hokuu1102/Gowin2026-PolySynth/release/20261103-final-52m293/evidence/hmi-white-percent-preview.png

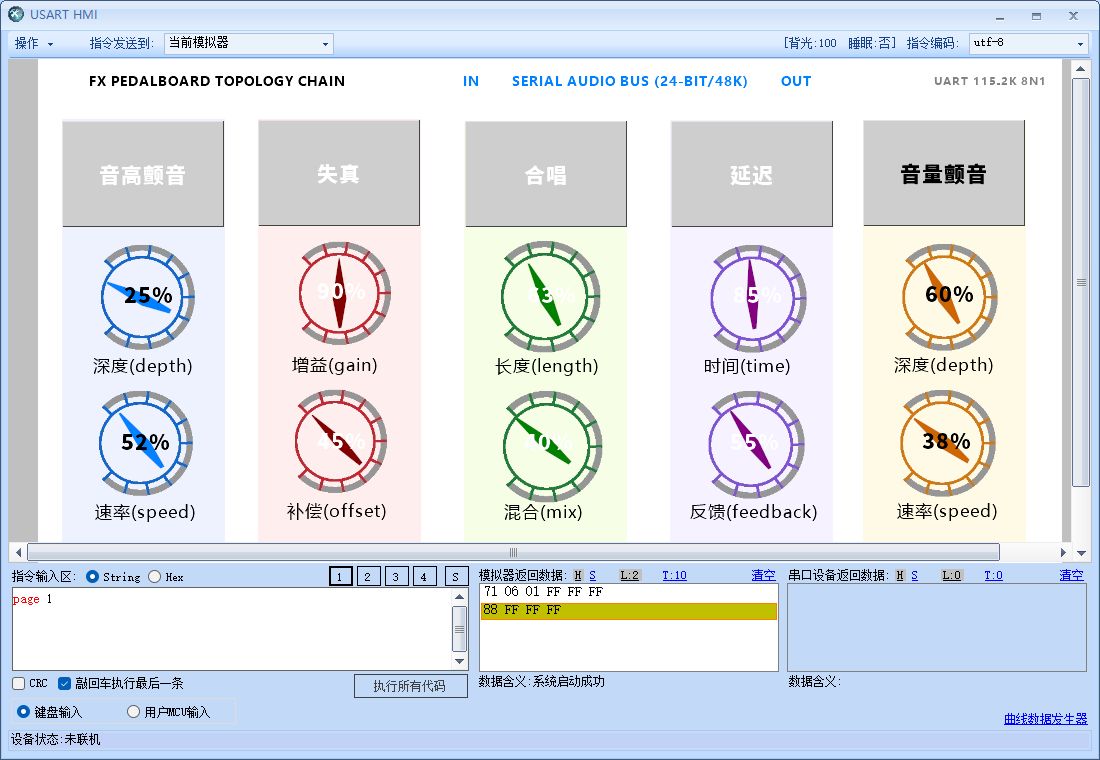
release/20261103-final-52m293/evidence/hmi-white-percent-preview.png
