hokuu1102/Gowin2026-PolySynth/README.md

# Gowin2026 PolySynth

当前工程面向 **GW5AT-LV60PG484AC1/I0 / 60K Console**。功能交付包括默认 FPGA 鼓机配置、ESP32-S3 BLE 曲库固件、验证证据与上板手册；具体文件、源码版本和时序状态以配套交付清单为准。尚未执行实机验收的项目标记待上板，不能用仿真通过替代。

## 当前操作与验证入口

- **[2026-11-03 最终配套工程与烧录件](release/20261103-final-52m293/README.md)**：当前 FPGA FS、串口屏 HMI/TFT、精确构建输入、校验和及上板操作。实际 50 MHz 门禁通过，报告 Fmax 52.293 MHz；效果器中间三列白字，两侧保持黑字。实机复测待执行。下列旧交付保留用于追溯。

- [2026-11-02 实时回传按键修正版及烧录文件](release/20261102-key15-uplink-53m319/README.md)：关闭后不再接收松键回传；实际 50 MHz 门禁通过，报告 Fmax 53.319 MHz，实机验收待进行。

- [2026-10-29 当前交付、烧录文件及与 59.245 MHz 版本的区别](release/20261029/交付说明.md)：保留完整功能，通过真实 50 MHz 工程门，实机验收待执行。
- [2026-10-29 时序优化与验证](files/20-代码/指引灯时序优化-20261029.md)：原约束下通过现有真实 50 MHz 工程门，Fmax 51.464 MHz，真实周期余量 +0.569 ns；16.4 ns 优化预算仍有 -3.031 ns，实板验收待执行。
- [2026-10-28 功能交付状态、原生时序与复现配置](release/20261028/交付版说明.md)：保留该日冻结交付及其时序状态，后续时序改进见上项。
- [完整上板验收手册](release/20261028/上板验收手册.md)：接线、所有面板操作、录制回传、BLE、效果器和长稳。
- [逐项验收记录](release/20261028/逐项验收记录.csv)：60 项，实板结果留待操作者填写。
- [交付要求](release/20261028/交付要求.md)：功能边界、固件和验证要求。
- [文档引用修复记录](release/20261028/文档引用修复记录.md)：已更正的路径与无法据此复核的历史材料说明。
- [已知问题与风险清单](files/20-代码/已知问题与风险清单.md)：K-173 起记录本轮修复、容量与时序边界。

## 功能与配置

16 轴 Hall 输入、力度跟随、四种音色、32 声部且每声部两个振荡器、滑音、延音、三档推子及独立锁定、鼓机、手弹键盘鼓、Looper、64 身份曲谱指引、双路 I2S 和 HDMI 波形/XY/FFT 均保留。默认 source-B 是鼓机；节拍器是 SEL_DRUM=0 的源配置，不与默认固件混称。

FX 为运行时可控，默认 mask=0、颤音 depth=0；可经 UART 0x71 帧启用失真、合唱、延迟并调颤音。混响和预留掩码位未实现。矩阵键 9 锁定当前推子档，键 15 松手切换实时回传（上电关闭；标定保留上电自动与串口 T）；E 循环三种视图。BLE 设备名为 FPGA2026-Synth2。以手册为准，不沿用历史 README 的编译期 FX 旁路、四档推子或长按 span 操作。

## 工程入口

FPGA 工程为 Gowin2026.gprj，约束为当前 CST/SDC，主顶层是 rtl/top.v。RTL 回归入口是 sim/tb_all.ps1，ESP32-S3 工程是 esp32/ble，网页工具是 esp32/tools/score_studio.html 与 upstream_studio.html。

最新固件必须由同版源码构建并按 SHA256 核对。仓库中的历史 impl、sim/evidence 或实验目录不自动代表当前交付固件；setup/hold/recovery/removal 均须读取实际原生报告，生成 .fs 不等于时序达标。

[2026-10-15 及此前 README 历史说明](files/历史/README-20261015-过时.md) 仅供追溯原版本。
