hokuu1102/Gowin2026-PolySynth/esp32/README.md

# 📡 ESP32 通路 · 工程目录

> **目的**：⭐ **把 ESP32 做成一根"无线的 USB 线"** ——
> ⭐ PC 怎么发、发多快，ESP32 原样照搬，⛔ **不看内容、⛔ 不生成音频**。
> ⭐ **外加**：把传输状态显示到 **2 寸串口屏**上。
>
> **主文档**：`files/20-代码/ESP32通路总体架构-20260922.md`（⚠️ **是 2026-09-22 的架构快照** —— 🔴🔴 **2026-10-01 更正**：⭐ **它的"1 Mbps / SPP / 先模式 A"口径已作废**，⭐ 该文件**顶部已加更正横幅**；⭐ **现行事实看本文 §〇之二**）
> **接续准备**：`files/20-代码/ESP32侧接续准备-20260923.md`（⭐ 对接点 + 联调清单；⚠️ 同为 09-23 快照）
> **FPGA 侧清单**：`files/20-代码/FPGA侧对接清单-ESP32通路-20260922.md`（⚠️ 同上，09-22 快照）
> ⭐⭐ **现行状态（⭐ 最先读这个）**：`files/00-总览/交接文档-20260930.md` §〇之二 + 本文 §〇之二

---

## 〇、⭐⭐ 本目录有两个版本（⭐ **2026-09-23 定案：主推 BLE**）

| 目录 | 芯片 | 蓝牙 | ⭐ 状态 |
|---|---|---|---|
| `bridge/` | 初代 ESP32 | **经典蓝牙 SPP** | ✅ **已编译通过**（⚠️ 但带 PSRAM 的板子买不到） |
| ⭐ **`ble/`** | ⭐ **ESP32-S3** | ⭐ **BLE** | ⭐⭐ **主推**（⭐ S3 那块**有 PSRAM** ⇒ 水池放得下整曲） |

🔴 **为什么会有两版（⭐ 这段历史很重要，⛔ 别重复走一遍）**：

```
① 最初：以为要用 S3
② 2026-09-22 更正：🔴 S3 没有经典蓝牙 BR/EDR ⇒ SPP 物理不可实现
   ⇒ 改用初代 ESP32（⛔ 但需要【带 PSRAM】的板子放整曲）
③ 2026-09-23 再更正：⚠️ 初代 ESP32 + PSRAM 的开发板【买不到】
   ⇒ ⭐ 回到 S3，改用 BLE —— ⭐ 用 PSRAM 换"PC 侧零限速"
```

⚠️ **两版的关系**：⭐ **并存、互不影响**，共用同一套 **9N 对齐**与**串口屏驱动**
（⚠️ 改一版⛔ 不会动到另一版）。

⭐ **要改哪一版**：⭐ **默认改 `ble/`**（主推）；⚠️ 只有明确要用 SPP 时才动 `bridge/`。

---

## 〇之二、⭐⭐ 2026-09-30 / 2026-10-01 新增（⚠️ 下文正文可能还是旧口径）

> 🔴🔴 **⚠️ 关于本文档里的 `file:line` 引用（⭐ 2026-10-01 加的说明，⭐ 请先读这条）**
>
> ⭐ **行号会随代码改动而【漂移】** —— ⚠️ 这是**已实测**过的：
> 🔴 2026-10-01 夜给 `ble_main.c` 的 `cmd_report_status()` 加了 `req=`/`up=` 两个字段
> （⭐ 共 **+21 行**）⇒ ⚠️ **该文件里【其后】所有行号整体 +21**
> ⇒ 🔴 文档里写"`case 0x03` 在 `:608`"的地方**当场就错了**（⭐ 实际在 `:629`）。
>
> ⭐⭐ **所以请按这个优先级读**：
> | ⭐ 优先 | ⭐ 怎么读 |
> |---|---|
> | **1️⃣ 最高** | ⭐ **看【符号名 / 代码片段】**（如 `if (h == s_handle_cmd)` 块、`cmd_report_status()`）—— ⭐ **它不会漂** |
> | **2️⃣** | ⭐ 看带 **"⭐ 截至 `<commit>`"** 的行号 —— ⭐ **那是钉住版本的，可信** |
> | **3️⃣ 最低** | ⚠️ **裸行号** —— 🔴 **只当"大概在哪"的线索**，⛔ 别当精确依据 |
>
> ⚠️ **本表第 4 行的行号已于 2026-10-01 夜按最新代码校正**；
> ⚠️ 其余文档里的裸行号**未逐条复核** ⇒ ⭐ **请按上表优先级自行判断**。

> 🔴🔴 **2026-10-01 第二轮文档审计**：⚠️ 本表第 **4**、**5** 行是**第一轮**写的，
> ⭐ 而当天夜里 `0xABF3` 加了起播/停止、`0xABF4` 扩成六组 ⇒ 🔴 **那两行已作废，已就地更正**。
> ⭐ 另补第 **10**~**17** 行（⭐ 2026-10-01 新增事实）。

| # | ⭐ 事实 | 证据（`file:line` / 实测） |
|---|---|---|
| **1** | ⭐ **波特率 = `500000`**（🔴 **不是 1 Mbps、不是 115200**） | `ble/main/ble_config.h` `BLE_BAUD 500000` · `uart_test/main/uart_test_main.c` `TEST_BAUD 500000` · `bridge/main/bridge_config.h` `BRIDGE_BAUD 500000` |
| **2** | ⭐⭐ **反向通路（FPGA→ESP32→BLE→PC）已打通** | ⭐ **2000 字节 round-trip 逐字节一致**；`esp32/evidence/反向通路验收-ESP32侧-20260930.md:4` · 设计 [反向通路对接单](<../files/20-代码/反向通路对接单-给FPGA侧-20260930.md>) |
| **3** | ⭐ **上行环形缓冲已实现** | `ble/main/up_ring.c` + `up_ring.h` —— **160 KB in PSRAM**，⭐ **"蓄水/放水"**：未订阅 ⇒ 蓄水（只存）；已订阅 ⇒ 放水；**满 ⇒ 拒绝新数据（保留最早的）** |
| **4** | ⭐⭐ **`0xABF3`(CMD) 有【四个】命令**：`0x01` 清池 · `0x02` 状态上报 · ⭐ **`0x03` = 起播（START）** · ⭐ **`0x04` = 停止（STOP）** | `ble/main/ble_main.c` 的 `if (h == s_handle_cmd)` 块 —— ⭐ `case 0x01` / `0x02` / `0x03` / `0x04`（⭐ 截至提交 `35036bf` 在 `:606` / `:611` / `:629` / `:634`；⚠️ **行号会随改动漂移，⛔ 别写死** ⇒ ⭐ 用 `grep -n "case 0x0" esp32/ble/main/ble_main.c` 现查）；⭐ 未知命令**计数不吞**（`cmd_unk`）<br>🔴🔴 **2026-10-01 更正**：⚠️ 原写「`0x01` = 清池 · `0x02` = 状态上报进 `0xABF4`；⚠️ **故意不做 start/stop**（⭐ 架构未定）」⇒ 🔴 **已作废**。⭐ 用户 2026-09-30 已裁定**走模式 B、起播键在 ESP32**（`files/20-代码/用户裁定结果-20260930.md` §〇）⇒ ⭐ 当晚补上 `0x03`/`0x04`（⭐ 复用 `start_action_play/stop`，⛔ 不另写一套，避免两条路径行为不一致） |
| **5** | ⭐⭐ **`0xABF4`(STAT) 返回【六组】**：`V1 mode=` · `pool=` · `ring=` · `ble=` · `uart=` · `frame=` · `cmd=`<br>⭐ **2026-10-01 起 `V1` 行带 `req=`（快照序号）/ `up=`（生成时刻）** ⇒ ⭐ **陈旧变得【可判定】**（⭐ 提交 `35036bf`：「C115 第二层修法：让 STAT 的【陈旧】可判定」）—— ⚠️ **连读两次 `req` 不变 ⇒ 🔴 数据是旧的**<br>🔴 **但它仍然是【拉取快照】** —— ⭐ **只有先发 `CMD 0x02` 才会刷新**（`cmd_report_status()` **只**被 `case 0x02` 调用，⭐ 截至 `35036bf` 在 `:613`）；⚠️ 不发就直读 ⇒ 拿到上一次的内容（⭐ 现在能靠 `req`/`up` **判定**它旧，⚠️ 但**不会自动刷新**）<br>🔴🔴 **尺寸警告（⭐ 2026-10-01 实测）**：⭐ 代表性样本 = **261 B**（`tools/stat_read.py --selftest` 的样本实测），🔴 **而 `char buf[256]`（`ble_main.c:352`）+ `s_val_stat[256]`（`gatt_svc.c:99`）⇒ 截断到 255 B** ⇒ ⚠️ **末组 `cmd=` 可能被切掉**（🔴 截至 `35036bf` **未见修复**，⚠️ 已列入开放问题） | `ble/main/ble_main.c` `cmd_report_status()`（`:336`；六条 `snprintf` 在 `:378`/`:380`/`:382`/`:384`/`:386`/`:388`/`:390`）；缓冲区 **256 B**（`ble/main/gatt_svc.c:99` `s_val_stat[256]`）；属性 **只读**（`ESP_GATT_PERM_READ` + `ESP_GATT_RSP_BY_APP`，`gatt_svc.c:180`~`:182`）⇒ ⭐ **固件不能 notify 它，客户端必须主动读**<br>🔴🔴 **2026-10-01 更正**：⚠️ 原写「⭐ 实测返回 `pool=0/18204 sent=0 ovf=0\|ring=0 u_drop=0/0`」⇒ 🔴 **那是旧的三组短格式，已作废**。⭐ 配套读工具 = `tools/stat_read.py`（⭐ 发 `0x02` → 读 → 逐字段核对）<br>⚠️ **字段列表一律以源码为准**（⭐ `cmd_report_status()`）—— ⛔ 别拿本表当接口契约 |
| **6** | ⭐ **一键端到端工具** | `tools/e2e_accept.py` —— 一条命令：清池 → BLE 灌 → 起播 → 抓包 → **判据表**（⭐ 通过退出码 0） |
| **7** | ⭐ **模式 B"放水"实测正确** | `rate=1919 tick/s`（⭐ 期望 1920）、`sent=200/200` |
| **8** | ⭐ **串口起播触发已实现** | UART1 RX（`GPIO18`）上的单字符 `S`/`X`/`R` —— ⭐ 由 `ble/main/ble_main.c` 的 `task_uart_to_ble` 解析 |
| **9** | 🔴 **按键脚 = `GPIO6`** | `ble/main/ble_config.h` `BLE_BTN_GPIO 6` —— 🔴🔴 **⛔ 不是 `GPIO0`**（⚠️ 原文档若写 `GPIO0` 即为陈旧断言） |
| **10** | 🔴🔴 **板载 WS2812 指示灯【已关闭】**：`WS2812_ENABLE=0` + `WS2812_CLEAR_ON_BOOT=1` ⇒ ⭐ **每次开机发一次全 0 清锁存，之后永不点亮** | `ble/main/ble_config.h:494` `WS2812_ENABLE 0` · `:502` `WS2812_CLEAR_ON_BOOT 1`；⭐ 板载 WS2812 数据脚 = **`GPIO48`**（`ble/main/ws2812.h` 头部【硬件事实】），⚠️ 且板上 **`R17` 出厂【断开】、必须短接跳线**它才可能亮<br>⚠️ **用户 2026-10-01 裁定「安全第一」**（`files/20-代码/今晚任务书-20261001.md:38`：🔴「灯保持关闭 —— ⛔ 不要重新打开 WS2812 指示」）<br>🔴🔴 **2026-10-01 更正**：⚠️ 2026-09-30 夜曾按用户原话「蓝牙连好了可以让灯亮一下」做成**连接指示灯**（`files/20-代码/用户裁定结果-20260930.md:123`）⇒ 🔴 **该设计已被推翻** ⇒ ⭐ **任何"连上 BLE 就亮灯"的说法都已作废** |
| **11** | ⭐ **板子 = `ESP32-S3-DevKitC-1`；flash = 16 MB**（🔴 不是 2 MB） | `ble/sdkconfig.defaults:40-41` `CONFIG_ESPTOOLPY_FLASHSIZE_16MB=y` / `CONFIG_ESPTOOLPY_FLASHSIZE="16MB"` |
| **12** | ⭐ **上行是【透明字节流】** —— ESP32 **不解释**上行内容 ⇒ ⭐ **68 字节的表同步帧可以原样穿过，⛔ 零固件改动** | `ble/main/ble_main.c:990` `up_ring_pop()` → `:997` `esp_ble_gatts_send_indicate()`（⭐ 中间没有按帧长切分、没有解析） |
| **13** | ⭐⭐ **上行帧长【按类型不同】**：音符类帧 = **14 B**；表同步（`0x10`）= **68 B** | `tools/evt2midi/frame_format.py` `FRAME_LEN_BY_TYPE`（`T_NOTE_ON`/`T_NOTE_OFF`/`T_CALIB`/`T_LOOPER` = **14**，`T_TABLESYNC` = **68**）<br>🔴 **⛔ 不要用固定 14 B 去切上行流**（⭐ 表帧会被切成 4 段 + 残留 ⇒ 后续全部错位） |
| **14** | ⭐ **MIDI 工具链（2026-10-01 新）** | `tools/evt2midi/`：`rec_upstream.py`（⭐ 录上行**原始字节**，⛔ 不解析）· `evt2midi.py`（→ `.mid`）· `frame_format.py`（⭐ **帧布局抽成的独立模块**，格式冻结时**只改一处**）—— ⭐ 详见 `tools/evt2midi/README.md` |
| **15** | ⭐ **`tools/stat_read.py`（2026-10-01 新）** | ⭐ 发 `CMD 0x02` → 读 `0xABF4` → 逐字段核对（⭐ 支持 `--selftest` / `--json`，⛔ 免硬件） |
| **16** | ⭐ **`tools/regress_live.py`（2026-10-01 新）** | ⭐ **真机回归**：CMD 命令集（`0x01` 清池 / `0x02` 状态 / `0x03` 起播 / `0x04` 停止 / `0xEE` 未知命令**必须计数**）+ **上行蓄水/放水**（⭐ 与 `e2e_accept.py` 分工：那个测**下行**，这个测**命令 + 上行**） |
| **17** | ⭐ **10 个验收/回归工具全部有 `--selftest`（⭐ 纯离线，⛔ 免硬件）** | `uart_rx_check` · `pool_pace_check` · `pool_math_check` · `uart_timing_check` · `trigger_and_capture` · `read_log` · `stat_read` · `e2e_accept` · `regress_live` · ⭐ **`rec_upstream`**<br>⭐ 提交 `764ee0f`：「**`rec_upstream.py` 补 `--selftest`（⭐ 全部 10 个工具现在都有）**」—— 🔴🔴 **2026-10-01 更正**：⚠️ 本轮审计**初稿**曾写「⭐ 8 个工具都有」+「⚠️ `rec_upstream.py` 仍【没有】」⇒ 🔴 **该断言在本审计进行中就被推翻**（⭐ 作者读到本表后**当场补上**，⭐ 提交信息原文：「⭐ 子代理在文档审计里【诚实指出】…⇒ 这是个真缺口 ⇒ 补上」）⇒ ⭐ **现值 = 10 个全有**<br>⭐ 非空洞性用**变异测试**证明（**22/22 变异体判红**，⭐ 不是"我断言它非空洞"）—— `files/20-代码/今晚任务书-20261001.md:67`；⭐ 全量判据数见 `files/20-代码/今晚任务书-20261001.md:81`（**275 项判据 / 0 RED**）<br>⚠️ **另**：`send_frames.py` / `send_frames_ble.py` / `loopback_check.py` **也各自带 `--selftest`**（⭐ 更早就有，⛔ 不在这 10 个的口径内） |

> 🔴🔴 **2026-10-01 审计警告：⛔ 别在本 worktree 里读 `rtl/` 或 `constr/` 的结论！**
>
> ⭐ `FPGA2026-esp32` 是**同一仓库的一个 `git worktree`**（分支 `feat/s3-ble`），
> 🔴 **它的 `rtl/` 与 `constr/` 都是【旧快照】**：
>
> | ⭐ 文件 | ⚠️ 本 worktree `FPGA2026-esp32\` | ⭐ 权威 `FPGA2026\` |
> |---|---|---|
> | `rtl/top.v` | **1804 行** | **4455 行** |
> | `constr/top.cst` | 17989 B · SHA256 `92DC1281…` | **29480 B · SHA256 `1C22CF12…`** |
>
> ⚠️ **行数怎么数的很重要**：⛔ PS 5.1 的 `Get-Content ... \| Measure-Object -Line` **会少算**
> （⭐ 实测同一个 `top.v`：PS 报 **1710**、python 按 UTF-8 报 **1804**；权威那份 PS 报 **4272**、python 报 **4455**）
> ⇒ ⭐ **行数一律用 `python -c "sum(1 for _ in open(p, encoding='utf-8'))"` 数**（同族 `C72`）。
> 📌 本段原先把这两个数写成「**1710 / 3970**」—— ⭐ **两个都不对**（⭐ 引用别人的行数时**当场重查**）。
>
> **① `rtl/` 的波特率**：⭐ 本 worktree 的 `rtl/top.v:311` 仍写 `.BAUD_DIV(50)` = 1 Mbps（⭐ **降档前**的状态），
> ⭐ 而**权威 FPGA 侧已降档 500 kbps**（⭐ 2026-10-01 实测行号）：
> `FPGA2026/rtl/top.v:702` `.BAUD_DIV(100)`（`u_uart_rx`）· `:945-946` `u_uart_tx .BAUD_DIV(100)` · `:785`/`:831` `.BAUD(500_000)`
> （⭐ 50 MHz ÷ 500 kbps = **100，整除 ⇒ 误差 0**）。
> 🔴 **⛔ 不要用本 worktree 的 `rtl/` 去反驳"500 k"** —— 那会得出**相反的错结论**。
> ⚠️ **注**：本段原先引用的 `:688`/`:715`/`:771`/`:815`/`:920` **已经失效**（权威 `top.v` 又改过）⇒
> 🔴 **连"警告"本身也在引用过期的行号** —— ⭐ 引用前请**当场重查**（同族 `C116`）。
>
> **② `constr/` 的后果更直接（⭐ 2026-10-01 实测）**：⚠️ 本 worktree 的 `constr/top.cst` 里 UART **还挂在板载 BL616**
> （`IO_LOC "uart_rx" V14` / `uart_tx U15`），
> ⭐ 而**权威副本里它早已搬到 `J9` 排针**：
> · `FPGA2026/constr/top.cst:364` `IO_LOC "uart_rx" D14;`（J9 · N26 · SDRAM0_A6 · BANK1，入）
> · `:366` `IO_LOC "uart_tx" D15;`（J9 · N25 · SDRAM0_A5 · BANK1，出）
> · `:352-353` 写明那一路是**给 USB-TTL 的**；`:357`「⚠️ **代价**：⭐ 板载 `BL616` 的那路 UART 从此不接」
> ⇒ ⭐ **照旧副本接线 ⇒ 接错脚。**
> ⭐ 另：`PMOD0`（含 `G21`/`G22`）在**权威副本里也仍未分配**（`FPGA2026/constr/top.cst:137`）
> ⇒ ⭐ **P1「等 `G21`/`G22` 分配」的阻塞是真的**，⛔ 不是过时结论。
>
> ⇒ ⭐ **核对 `rtl/` / `constr/` 一律去 `C:\Users\hokuu\Desktop\FPGA\FPGA2026\`**（⭐ 证据：`git worktree list`）。
> ⭐⭐ **机械判据（⛔ 别靠"我记得它旧"）**：⭐ **比 SHA256 / 比文件大小**，或**直接读权威路径**。
> 📌 **本警告只覆盖 `rtl/` 时反而更危险** —— ⚠️ 一旦某处标了警告，人就会**默认其余部分是新的**
> （⭐ 2026-10-01 实测：本人正是照旧 `constr/` 得出了错结论）。

---

## 一、⭐⭐ 先看你要做哪件事

| 你想做什么 | ⭐ 去哪 |
|---|---|
| ⭐⭐ **拿到板子第一次上机** | ⭐⭐ **`esp32/上机指南.md`**（⭐ **从裸板到验收判据，照它做**） |
| ⭐ **编译/烧录固件** | ⭐ **`ble/README.md`**（BLE 版，主推）· `bridge/README.md`（SPP 版） |
| ⭐ **接串口屏、做界面** | ⭐ **`串口屏控件清单.md`** → `串口屏上位机使用说明.md` → `串口屏指令表.md` |
| ⭐ **不接 FPGA 先验证** | ⭐ **`tools/send_frames.py`**（PC 侧"假 FPGA"发送工具，⭐ `--selftest` 免硬件） |
| ⚠️ **验证 9N 对齐/回环** | `tools/loopback_check.py`（7 条判据 + 帧内空隙判据） |
| ⭐ **模式 B 的算术复核** | `tools/pool_math_check.py` |
| ⭐⭐ **读 `0xABF4` 状态（六组 221 B）** | ⭐ **`tools/stat_read.py`**（⭐ 发 `CMD 0x02` → 读 → 逐字段核对；🔴 **`0xABF4` 是拉取快照，⛔ 不发 `0x02` 就读到旧内容**） |
| ⭐⭐ **真机回归（命令 + 上行）** | ⭐ **`tools/regress_live.py`**（⭐ `0x01`/`0x02`/`0x03`/`0x04` + 上行蓄水/放水） |
| ⭐ **把 FPGA 回传事件还原成 MIDI** | ⭐ **`tools/evt2midi/`**（⭐ `rec_upstream.py` 录 → `evt2midi.py` 转 → `song.mid`；⭐ 帧布局在 `frame_format.py`） |
| ⭐ **跑全部离线自检** | ⭐ **`tools/selftest_all.py`** —— ⭐ **一条命令跑完全部**（⭐ 自动枚举 `tools/` 与 `tools/evt2midi/`，⭐ 单一退出码 0 = 全过）<br>⭐ 实测：**15 个脚本 / 262 项 OK / 0 RED**（⭐ 提交 `c5c3d43`）<br>⚠️ 枚举而非手写清单 ⇒ ⭐ **不会漏**（⭐ 我手工列清单时漏过 3 个） |
| ⭐ **10 个验收/回归工具都带 `--selftest`** | ⭐ 见 §〇之二 第 **17** 行（⭐ 含 `rec_upstream.py`）—— ⚠️ **但用 `selftest_all.py` 跑，⛔ 别手敲清单** |
| ⚠️ **联调前要核对什么** | `files/20-代码/ESP32侧接续准备-20260923.md` §六 |

---

## 二、🔴 关键事实（⭐ 两版通用，⛔ 不要重新讨论）

### 2.1 ⭐ **9N 对齐**（⭐ 整个通路最核心的纪律）

| 事实 | 后果 |
|---|---|
| ⚠️ **RFCOMM / BLE 都是字节流，不保留 `write()` 边界** | ⚠️ **一个 9 字节帧可能被切成两次回调** |
| 🔴 FPGA 的空闲归位**只在帧中途触发** | 🔴 **帧内被打断 = 截帧**（⚠️ 静默少几个音） |
| 门限 **160 µs** @1 Mbps | ⚠️ 远超 BLE 包间隔（7.5~30 ms）<br>⚠️ **2026-09-30 注**：⭐ 实际链路已跑 **500 kbps** ⇒ 门限 = **320 µs**（⭐ 但"远超包间隔"的结论**不变**，⭐ 见 §2.1 更正） |

⇒ ⭐ **铁律三条**：
1. ⭐ **写 UART 恒为 9 的整数倍**（余数留到下次）
2. ⭐ **一帧 9 字节一次写入**
3. ⭐ **块大小也是 9N**（⚠️ **1026 = 9×114**，⛔ **1024 不是**）

### 2.2 ⭐⭐ 三种 9 字节块（靠**帧头**区分，⛔ 不靠位置）

| 帧头 | ⭐ 类型 | ESP32 动作 |
|---|---|---|
| **`0xA5`**（非全 A5） | ⭐ **事件帧** | ✅ **转发给 FPGA** |
| **`0xA5`**（全 9 字节都是） | ⭐ **复位标记** | ⛔ 丢弃 |
| ⭐ **`0x00`** | ⭐ **总数帧**（byte1..8 = 大端总事件数） | ⛔ **自己留下并解析** |
| 其他 | 🔴 未知 | ⛔ 丢弃 + 计数（⚠️ 应恒为 0） |

🔴 **为什么过滤必须在 ESP32 做**：⭐ FPGA **只认 `0xA5` 帧头** ——
别的帧头到了它那里 ⇒ ⚠️ `hdr_err_cnt_o++`（⭐ 本该是 0，是验收判据）
且载荷被当成一个**真事件** ⇒ 🔴 **弹出随机音符**。

### 2.3 ⭐ 默认模式 B（二级水池）

| | ⭐ 模式 B（默认） |
|---|---|
| ESP32 做什么 | ⭐ **缓存整曲**（PSRAM）+ **自己按谱子时间放水** |
| ⭐ PC 侧要做什么 | ⭐⭐ **一口气灌完，⛔ 零限速代码** |
| 🔴 关键约束 | ⚠️ **放水必须按 tick 限流** —— ⛔ 否则 92 ms 就灌满 FPGA 的 8 KB 缓冲 |

---

## 三、⚠️ 开工前先确认芯片（⭐ 判据随版本不同）

🔴 **`bridge/`（SPP 版）需要用【初代 ESP32】** ——
**S3 没有经典蓝牙 BR/EDR** ⇒ **SPP 在 S3 上物理不可实现**。

| # | 方法 | 判据 |
|---|---|---|
| **1** | 看模组丝印 | SPP 版应印 **`ESP32-WROOM-32E`**；⭐ **BLE 版应印 `ESP32-S3-*`** |
| **2** | ⭐ **读芯片 ID**（最确凿） | `esptool` 的 `chip_id` ⇒ SPP 版报 `ESP32-D0WD-V3`；⭐ BLE 版报 `ESP32-S3` |
| **3** | ⚠️ 带 PSRAM 吗 | ⭐ **BLE 版必须要**（⚠️ 模组型号带 `R` 后缀，如 `N16R8`） |

```powershell
# ⭐ 一句话定死芯片型号
python -m esptool --port COM7 chip_id
#    SPP 版期望：Chip is ESP32-D0WD-V3
#    BLE 版期望：Chip is ESP32-S3
```

> ⚠️ **为什么必须实测**：⚠️ 市面上有把 S2/S3 当"ESP32"卖的，
> ⚠️ 而**商品简介常常只写 WiFi、不提蓝牙** —— ⛔ **不能作为判据**。

---

```
PC ──BLE──> ESP32-S3 ──UART1──> FPGA      ← 正向：帧流
PC ──BLE──> ESP32-S3 ──UART2──> 串口屏    ← ⭐ 状态显示（独立 UART）
PC ──USB-TTL──> ESP32 的 UART1 RX         ← ⚠️ 不接 FPGA 时，用 USB-TTL 当"假 FPGA"
```

| 项 | ⭐ BLE 版（`ble/`） | ⚠️ SPP 版（`bridge/`） |
|---|---|---|
| 给 FPGA 的 UART | ⭐ **UART1：`GPIO17`=TX / `GPIO18`=RX** | UART2：`GPIO17`/`GPIO18` |
| 给串口屏的 UART | ⭐ **UART2：`GPIO4`=TX / `GPIO5`=RX** | ⚠️ UART1（⚠️ 与 BLE 版**正好相反**） |
| **波特率（给 FPGA）** | ⭐ **`500000`**（⚠️ 固件可配置）<br>🔴🔴 **2026-09-30 更正**：⚠️ 原写「1 Mbps」⇒ 🔴 **已作废**。⭐ 现值 = **500000**（`esp32/ble/main/ble_config.h` `BLE_BAUD 500000`·`esp32/uart_test/main/uart_test_main.c` `TEST_BAUD 500000`·`esp32/bridge/main/bridge_config.h` `BRIDGE_BAUD 500000`）；⭐ FPGA 侧 2026-09-24 已降档（`FPGA2026/rtl/top.v:682/709/765/809/914`） | 同 |
| 格式 | 8N1，无流控，3.3 V | 同 |

⚠️ **两版的 UART 编号【正好相反】**（⭐ 因为 S3 的可用引脚与外设不同）——
⛔ **别照抄另一版的引脚**。

⚠️ **ESP32 与对端之间要【交叉接】**：TX → 对方的 RX，反之亦然。

> ⚠️ **S3 的引脚注意**：`GPIO19/20` 是**原生 USB**（⛔ 别当普通串口）；
> 模组用**八线 PSRAM** 时 `GPIO35/36/37` 被占用 ⇒ ⭐ 改引脚前查模组 datasheet。

---

## 三、⭐⭐ 最关键的一条纪律

> 🔴🔴 **写 UART 的字节数【恒为 9 的整数倍】**（余数留到下次）。

⚠️ **为什么**：**RFCOMM 是【字节流】，⛔ 不保留 `write()` 的边界** ⇒
⚠️ PC 的一次 `write(9 字节)` 到 ESP32 **可能变成两次回调**，中间隔一个任务调度周期
⇒ 🔴 远超 FPGA 的 160 µs 归位门限 ⇒ **静默截帧**。

| # | 要求 |
|---|---|
| **1** | ⭐ **维护一个 0–8 的余数计数器**，只有凑够 9N 才写 UART |
| **2** | ⭐ **块大小也必须是 9N** —— ⚠️ **1024 不是 9 的倍数**（`1024 = 9×113 + 7`）⇒ 🔴 **边界落在帧中间**<br>⭐ 正确值：**1026 B = 114 帧** |
| **3** | 🔴 **一帧的 9 字节【一次写入】**（⛔ 不分 9 次、⛔ 中间不 `vTaskDelay`） |

✅ **这仍然不看内容、不改内容** ⇒ ⭐ **仍然算透传**。

---

## 四、⭐ 目录结构

```
esp32/
├── ble/          ⭐ 主推固件工程（ESP32-S3 + BLE）
│   └── main/     ⭐ 含 up_ring.c/.h（160 KB PSRAM 上行缓冲，蓄水/放水）
├── bridge/      固件工程（初代 ESP32 + SPP）
│                 ⭐ 模式 A：纯透传（先做）
│                 ⚠️ 模式 B：二级水池（A 跑通后再上）
├── uart_test/    ⚠️ 诊断固件（⭐ 独立的"UART 物理层"对照组工程）
├── tools/       回环自测 + 端到端脚本
│                 ⭐ 含【到达时间戳】判据（⚠️ 只比对内容测不出帧内空隙）
│                 ⭐ e2e_accept.py = 一键端到端验收（清池→灌→起播→抓包→判据表）
│                 ⭐ stat_read.py = 发 CMD 0x02 读 0xABF4 并逐字段核对
│                 ⭐ regress_live.py = 真机回归（CMD 命令集 + 上行蓄水/放水）
│                 ⭐ evt2midi/ = FPGA 回传事件 → MIDI
│                    （rec_upstream.py 录 · evt2midi.py 转 · frame_format.py 帧布局）
├── evidence/    实测矩阵日志（⭐ 空口说"能通"不算）
└── README.md    本文件
```

> 🔴🔴 **2026-09-30 更正**：⚠️ 本块原文**只列了 `bridge/` 与 `tools/`** ⇒
> 🔴 **漏了 `ble/`（主推版）与 `uart_test/`，也没提 `up_ring`** —— ⭐ 已按上表补齐。
>
> 🔴🔴 **2026-10-01 更正（第二轮）**：⚠️ `tools/` 下原文只提了 `e2e_accept.py` ⇒
> 🔴 **漏了 `stat_read.py` / `regress_live.py` / `esp32/tools/evt2midi/`** —— ⭐ 已补齐（⭐ 证据见 §〇之二 第 **14**~**16** 行）。

---

## 五、⚠️ 边界（⛔ 硬约束）

| # | 约束 |
|---|---|
| **1** | 🔴 **⛔ 不要动 `rtl/` `constr/` `tools/`** —— ⚠️ **另有其人负责**，⭐ 而且那边**正在改 `rtl/`** |
| **2** | ⭐ **本目录（`esp32/`）是 ESP32 侧唯一的工作区** |
| **3** | ⚠️ **电平 3.3 V**，⛔ 别接 5 V |
| **4** | ⭐ **ESP32 ⛔ 绝不碰音频/视觉的【生成】**（🔴 合规红线） |

---

## 附 · 关联文档

| 想看什么 | 去哪 |
|---|---|
| ⭐⭐ ESP32 侧主文档（架构） | `files/20-代码/ESP32通路总体架构-20260922.md` |
| ⭐ ESP32 侧交接 | `files/20-代码/ESP32通路交接文档-20260922.md` |
| ⭐ FPGA 侧对接清单 | `files/20-代码/FPGA侧对接清单-ESP32通路-20260922.md` |
| ⭐ 事件格式（冻结） | `files/20-代码/play_seq接口冻结契约.md` |
