hokuu1102/Gowin2026-PolySynth/esp32/_drafts/README.md

# 📁 历史草案目录 · 已作废

> ⚠️ **本目录只放【已被推翻】的中间产物**，⭐ **不要照它做**。

---

## `ESP32交接文档-BLE草案-20260922.patch`

| 项 | 说明 |
|---|---|
| **是什么** | 2026-09-22 22:43，把 `files/20-代码/ESP32通路交接文档-20260922.md` **改成 BLE 方案**的那次改动补丁 |
| 🔴 **状态** | ⭐ **已作废**（⚠️ **⛔ 不要应用它**） |
| **为什么作废** | 🔴 **它的前提是错的** —— 当时认定"芯片只能是 S3 ⇒ 只能走 BLE"。<br>⭐ **但用户手上有初代 ESP32（`ESP32-WROOM-32E`）**，⚠️ **它有经典蓝牙** ⇒ ⭐ **方案定为 SPP**（⭐ 比 BLE 明显更优：PC 配对即 `COMx`、`evt2uart.py` 零改动、水池需求从 92.6 KB 降到几 KB） |
| **为什么不删** | ⭐ 项目纪律：**推翻旧结论要保留"错误 → 修正"痕迹**（⛔ 不删历史） |
| ⚠️ **注意** | 🔴 **这个补丁已经【打不上】了** —— 交接文档此后被完全重写，⚠️ 上下文早已不匹配 |

## ⭐ 想知道"最后怎么定的"，看这里

| 想看什么 | 去哪 |
|---|---|
| ⭐⭐ **最终方案（主文档）** | `files/20-代码/ESP32通路总体架构-20260922.md` |
| ⭐ **8 处更正的完整记录** | `files/20-代码/ESP32通路交接文档-20260922.md` **§十一 更正记录** |
| ⭐ FPGA 侧对接清单 | `files/20-代码/FPGA侧对接清单-ESP32通路-20260922.md` |
