hokuu1102/Gowin2026-PolySynth/sim/evidence/esp32-uart-20261011/README.md

# ESP32 独立 UART 接线（2026-10-11）

> ⭐ 依据**用户 2026-10-11 的接线定案** ＋ ⭐ 「files/10-硬件/Console拓展板接线需求-20261003.md」（历史引用，当前未收录） ✅
> ⭐ 本轮把 **ESP32 那一路真的接上**（⭐ 在此之前它**一个端口悬空、一个端口恒 1** ✅）

---

## 〇、接线定案（⭐ 用户原话）

> *"console接线里面应该有对应的串口，**串口屏和调试用一个串口**，然后 **esp32 单独用另一对串口**"*

⭐ 与接线文档**逐条对上**（⭐ `Console拓展板接线需求-20261003.md`）：

| # | 行 | 内容 |
|---|---|---|
| 1 | `:562` | ⭐ 命令 / 调试 UART **500000 8N1** → `D15`/`D14` → `XH_SCREEN` ✅ |
| 2 | `:563` | ⭐ 串口屏 **共用同一条** UART（⭐ *"与调试口**不能同时用**"* ✅） |
| 3 | `:564` | ⭐ **ESP32（BLE 回传 / 上位机）独立 UART** → `G21`/`G22` → `XH_ESP32` ✅ |
| 4 | `:610` | ⭐ *"串口屏与命令口撞字母（`P0-4`）… ⭐ **ESP32 那一路已给独立 UART，可作为规避手段**"* ✅ |

---

## 一、⭐ 改之前的状态（⭐ 两个端口都没接）

| 端口 | 引脚 | 🔴 改前 |
|---|---|---|
| `esp_uart_rx_i` | `G22` | ⭐ **无人消费** —— 只被 OR 进 `reserved_in_xor` 这个"保活"异或 ✅ |
| `esp_uart_tx_o` | `G21` | ⭐ **恒 `1'b1`**（空闲高）⇒ 🔴 **什么都不发** ✅ |

⭐ 而 `top.v` **自己写明了接入纪律**（⭐ `:5390` 附近）：

> *"接入功能逻辑时 ⇒ ⭐ **必须删掉该端口在这里的驱动行**（⛔ 否则**多驱动** ⇒ 综合报错）；
> 输入侧还要把它**从 `reserved_in_xor` 里摘掉**（交给新逻辑消费）"* ✅

---

## 二、✅ 改了什么（⭐ 5 处）

| # | 位置 | 改动 |
|---|---|---|
| ① | ⭐ `top.v` | ⭐ 新增 `uart_rx #(.BAUD_DIV(100)) u_uart_rx_esp`（⭐ `rx_i = esp_uart_rx_i`，⭐ `G22` ✅） |
| ② | ⭐ `top.v` | ⭐ `evt_uart_rx`（**曲谱**）的 `rx_done_i`/`rx_data_i` ⭐ **改接 ESP32 那一路** ✅ |
| ③ | ⭐ `top.v` | ⭐ 新增 `uart_tx #(.BAUD_DIV(100)) u_uart_tx_esp`，⭐ **与板载口镜像同一份回包**（`txf_start`/`txf_data`）✅ |
| ④ | ⭐ `top.v` | ⛔ **删掉** `assign esp_uart_tx_o = 1'b1;`（⭐ 多驱动纪律 ✅） |
| ⑤ | ⭐ `top.v` | ⛔ **把 `esp_uart_rx_i` 从 `reserved_in_xor` 摘掉**（⭐ 10 个输入 → 9 个 ✅） |

⭐ **波特率**：⭐ 两侧**已同档** —— ⭐ FPGA `BAUD_DIV = 50 MHz / 500 kbps = 100`（**整除 ⇒ 零误差**）
⭐ ＝ ESP32 固件的 `BLE_BAUD 500000` ✅
（⭐ 接线文档 `:562` 的旧值 115200 已过时；⭐ ESP32 侧 `README.md` §〇之二 明确改为 **500000** ✅）

---

## 三、⭐⭐ 为什么这一步不只是"接线"—— ⭐ 它**根治了一条 P1**

🔴 **`P0-02` 那个门控，根因是"曲谱与串口屏/命令共用一条线"** ✅

```text
改前：uart_rx（板载）─┬─► uart_ui（串口屏）
                     ├─► calib_cmd（命令）
                     └─► evt_uart_rx（曲谱）   ← 🔴 三者抢同一条线
     🔴 屏帧/命令流的【载荷】里出现 0xA5 ⇒ 被曲谱接收器当帧头 ⇒ 伪事件 ⇒ 永久挂音
     ⚠️ P0-02 的修法"别人帧内就不给曲谱字节"【只能治标】：
        ⭐ 0xA5 落在【帧间空隙】时仍可能误判 ⇒ 🔴 那条 P1 一直挂着 ✅

改后：uart_rx（板载）─┬─► uart_ui（串口屏）
                     └─► calib_cmd（命令）      ← ⭐ 只剩"屏 + 命令"
     esp_uart_rx_i（G22）─► evt_uart_rx（曲谱）  ← ⭐ 【独立一条线】
     ⇒ ✅ 那条 P1 的【根因消失】：⭐ 两条线**结构上不可能再互相误判** ✅
     ⇒ ✅ 而且**曲谱带宽不再被屏刷新挤占** ✅
```

📌 ⭐ **顺带**：⭐ 那个门控**必须删掉**（⭐ 而不是留着）——
⚠️ 否则**串口屏每刷一帧，曲谱字节就会被吞**（⭐ 两条线本该互不相干 ✅）
⇒ ⭐ 这也意味着 `ui_in_frame` / `cmd_idx` 在 `top.v` 里**从此没有消费者**
（⭐ 综合会剪掉；⭐ 而 `uart_ui`/`calib_cmd` 自己的帧解析**照常工作** ✅）

---

## 四、⭐ 判据（⭐ 3 条，⭐ 全在 `tb/w3b/tb_top_score_path.sv` 的 G 段）

| # | 判据 | ⭐ 打的是什么 |
|---|---|---|
| `Ga` | ⭐ 在**板载口**发一帧**真曲谱** ⇒ ⭐ `eu_frame_cnt` **不许变** | ⭐ **两条线各归各**（⭐ 改前必红 ✅） |
| `Ga2` | ⭐ 同一次 ⇒ ⭐ `play_seq.evt_cnt_o` **不许变** | ⭐ 同上（⭐ 行为层 ✅） |
| `Gb` | ⭐ 在板载口发 `'P'` ⇒ ⭐ **`esp_uart_tx_o` 必须出现起始位（拉低）** | ⭐ **ESP32 的 TX 是【活】的**（⭐ 改前恒 1 ⇒ 必红 ✅） |

⭐ **`Gb` 为什么用 `'P'`**：⭐ 它是现成的诊断命令 ⇒ ⭐ `pos_probe` 会推回包进 `u_tx_fifo`
⇒ ⭐ 两个 `uart_tx` **镜像**同时发 ⇒ ⭐ **ESP32 那一路必然出现起始位** ✅

---

## 五、⭐⭐ 变异体测试（⭐ 而且它**抓到了我自己判据的缺陷**）

⭐ 变异体 = **把接线退回改前状态**（⭐ 即 `rx_done_i(ur_done)` ＋ `tx_o()` 不接）✅

| 判据 | ⭐ 变异体下 |
|---|---|
| `Gb` | 🔴 **红** ✅（⭐ ESP32 的 TX 永远不拉低） |
| `Ga2` | 🔴 **红** ✅（⭐ 板载口**真的**喂进了曲谱 ⇒ 事件被消费） |
| 🔴 **`Ga`（第一版）** | ⚠️ **假绿** ❌ |

### 🔴 `Ga` 第一版为什么假绿（⭐ 值得记）

⭐ 第一版查的是 **`eb_rd_valid`**（⭐ 缓冲非空标志）——
⚠️ 而 `tick = 1` 的事件**早已到期** ⇒ ⭐ `play_seq` 会**立刻把它取走**
⇒ 🔴 **等我查的时候 `eb_rd_valid` 已经回到 0** ⇒ ⭐ **判据侥幸通过** ✅

✅ **已改成查【帧计数】`eu_frame_cnt`** —— ⭐ 它是**单调计数器**：
⭐ 一旦收满一帧就 `+1`、⭐ **取走也⛔ 不会回退** ⇒ ⭐ **不可能假绿** ✅

📌 ⭐ **这正是"变异体测试"的价值**：⭐ 它在**修法正确**的情况下，
⭐ 也暴露了"**判据本身太弱**" ✅（⭐ 与 `P1-18` 的 `2a`、⭐ `P0-31` 的 `W2` **同一族** ✅）

⚠️ ⭐ **诚实标注**：⭐ 新 `Ga`（帧计数版）的"能红"是**由 `Ga2` 的红反推**的 ——
⭐ `Ga2` 红证明"板载帧确实走完了 `evt_uart_rx`"⇒ ⭐ `frame_cnt_o` 必然 `+1`
⇒ ⭐ 新 `Ga` 必然红 ✅
📌 ⭐ **没有直接重跑变异体**：⭐ 那次跑了 **430 s**（⭐ 见 §六），⚠️ 不值得为它再跑一遍 ✅

---

## 六、⚠️ 一个**实测的坑**：这个 tb 的耗时对"接线"极敏感

| 配置 | ⭐ 实测耗时 |
|---|---|
| ✅ 正确接线（⭐ 曲谱在 ESP32 口） | ⭐ **12.7 s** |
| 🔴 变异体（⭐ 曲谱退回板载口） | 🔴 **430 s**（⭐ **34 倍**） |

⭐ 而**第一版**（⭐ `tick=3` ＋ 60000 拍监视）在正确接线下就 **> 120 s**
⇒ ⚠️ 报 `TIMEOUT`，⭐ 而日志**只有 198 字节、连第一行 `$display` 都没有** ✅
📌 ⭐ 这正是本项目**已记录**的陷阱：⭐ **"日志缓冲会让零输出骗人"**（⭐ 被掐时输出还没落盘 ✅）

✅ **两处处置**：
1. ⭐ **缩短 tb**：⭐ `tick` 3 → **1**（⭐ 判据强度不变：⭐ `tick=1` 仍能证"先存后发"，
   ⭐ 而 `tick=0` 才会让判据变空 ✅）＋ ⭐ 监视 60000 → **12000 拍** ✅
2. ⭐ **`tb_top_score_path` 进 `tb_all.ps1` 的 `$heavyTb`**（⭐ 300 s 预算）——
   ⚠️ 理由**不是**它平时慢（⭐ 12.7 s ✅），⭐ 而是**变异体测试**要拿同一份 tb
   配被改过的 RTL 跑 ⇒ ⭐ 那种配置下 **430 s** ⇒ 🔴 默认 120 s 必误报 ✅
   （⭐ 与 `K-94` / `K-161` **同一族**：⭐ 撞预算 ≠ 挂死 ✅）

---

## 八、⭐ 综合 / PnR / 回归（⭐ 实测）

### ⭐ 资源（⭐ 干净重建口径，⭐ 与上一轮 `P1-59` 对比）

| 资源 | ⭐ 改前 | ✅ 改后 | ⭐ 差值 |
|---|---|---|---|
| `T_Lut` | 27622 | **27689** | ⭐ **+67** |
| `T_Register` | 17627 | **17690** | ⭐ **+63** |
| `T_Alu` | 8297 | **8296** | ⭐ **−1** ✅ |
| `T_Bsram` | 34 | **34** | ⭐ **0** ✅ |

📌 ⭐ **怎么读**：⭐ 两个新 UART（⭐ 一个 `uart_rx` ＋ ⭐ 一个 `uart_tx`）＝ ⭐ 同步器 ＋ FSM ＋ 分频计数器
⇒ ⭐ `+63 FF` / ⭐ `+67 LUT` **与预期相符** ✅（⭐ **零 BSRAM** ✅）
📌 ⭐ 引脚：⭐ `G22`（`esp_uart_rx_i`）与 ⭐ `G21`（`esp_uart_tx_o`）**都在网表里**，
⭐ 且 `esp_uart_tx_o` 现在是**真输出**（⛔ 不再是常量）✅

### ⭐ PnR

| 项 | ⭐ 值 |
|---|---|
| ⭐ 违例 | ⭐ **`0 setup / 0 hold`** ✅ |
| ⭐ `Actual Fmax` | ⭐ **56.397 MHz** ⇒ ⭐ **真实余量 `+2.28 ns`** ✅ |
| ⭐ `CLS` / `BSRAM` | ⭐ 24202/29952 = **81%** · ⭐ 37/118 = 32% ✅ |
| ⭐ `buildExit` | ⭐ **`0`** ✅ |
| ⭐ `sha256` | ⭐ **`9145A48B0715180B414F8F484DCEDEAAE08C96126DB62CA9B985136634AEB5F2`** |
| ⭐ 大小 | ⭐ 19094 KB |

### ⭐⭐ 6 道门全 OK（⭐ 逐字）

```text
OK  NL0002 gate: 3 swept module(s), all whitelisted
OK  P1-53 gate: 0 parameter-guard violations (EX3793 absent)
    HOLD worst slack = 0.128 ns  (review baseline 0.137)   u_looper hits = 5
WARN: P0-25 -- HOLD worst slack 0.128 ns is BELOW the 0.137 baseline (but >= 0.05)
OK  P0-25 gate: HOLD worst slack 0.128 ns >= 0.05 ns
OK  P0-23 gate: 0 async-reset sensitivity lists
OK  P0-26 gate: all 2 generated clock(s) have an Fmax row: serial_clk, pixel_clk
OK  P0-29 gate: all 6 critical observability wires have a consumer
=== Gowin build finished, exit code 0 ===
```

### 🔴⚠️ ⭐ **必须如实记的一条：HOLD 余量降到了审查基线【之下】**

| 轮次 | ⭐ `HOLD worst slack` |
|---|---|
| ⭐ 审查基线 | ⭐ 0.137 ns |
| ⭐ `P1-18` 之后 | ⭐ 0.183 ns |
| ⭐ `P1-59` 之后 | ⭐ 0.146 ns |
| 🔴 **本轮（ESP32 接线）之后** | 🔴 **0.128 ns**（⭐ **< 0.137 基线** ⇒ ⭐ **门报了 `WARN`** ✅） |

📌 ⭐ **门仍然通过**（⭐ 判据是 `>= 0.05 ns` ✅），⚠️ **但这是本周期第一次掉到基线以下** ✅
⭐ **归因（⭐ 不猜）**：⭐ 本改动**只加了两个 UART**（⭐ 全是**独立的小时序域**，
⭐ 与 `u_looper` 那条最差路径**没有逻辑关系** ✅）
⇒ ⭐ 与项目已记录的结论一致：⭐ **`HOLD` 是布局敏感项、无 RTL 解**
（⭐ 交接文档 §四-2：⭐ 那条路径"**HOLD 无 RTL 解**" ✅）
📌 ⭐ **本轮的 `u_looper hits = 5`**（⭐ `P1-59` 时是 14、⭐ `P1-18` 时是 0）
⇒ ⭐ 同一个数在 **0 / 14 / 5** 之间跳 ⇒ ⭐ **进一步证明它是布局噪声主导** ✅
🔴 **⛔ 不要把它归因给 ESP32 接线**；⭐ 但要**盯着**：⚠️ 若下次继续掉到接近 0.05
⇒ ⭐ 就该按交接文档 §四-2 的预案处理（⭐ 给 `u_looper` 的 BSRAM 读口加流水 ✅）

## 七、⚠️ 诚实标注（⭐ 还没做的）

⭐ **"曲谱灌水"现在通了**（⭐ 端到端见 `tb_top_score_path` 的 A/B/C/D/E/F 段 ✅）
🔴 **但"录制回传"还差一步**：⭐ `looper` **没有读出口** ✅

| # | 缺什么 | 说明 |
|---|---|---|
| 1 | 🔴 **`looper` 的 dump 端口** | ⭐ 它只有 `play_*`（**本地**回放）＋ 计数可观测量（`evt_cnt_flat_o`/`full_o`/`drop_cnt_o`/`overflow_o`）⭐ **没有** `rd_addr`/`rd_data`/`rd_valid` ⇒ ⭐ 录到的内容**读不出来** ✅ |
| 2 | ⭐ 导出状态机 ＋ 帧格式 | ⭐ 一个"按地址回读 → 推 `u_tx_fifo`"的 FSM ＋ ⭐ 与 PC 约定的帧头（⭐ 可复用 `0xA5` 那套 ✅） |
| 3 | ⭐ 缓冲的 `high_water_o`（高水位 sticky） | ⭐ ESP32 侧清单 `FPGA侧对接清单-ESP32通路-20260922.md` §2.3 的 **L1 要求**：⭐ "在真正丢失**之前**就置位" ⇒ ⭐ 我的 `evt_buf` 有 `cnt_o`（水位）＋ `ovf_o`（**丢了才**置位）⭐ **缺 high_water** ✅ |
| 4 | ⭐ 守恒等式（⭐ 清单 §三 五条） | `frame_cnt` == `pushed` == `play_seq.evt_cnt + 水位` == `merged+drop+collision` == `受理+event_lost` ⇒ ⭐ 多数计数器已有，缺**把缓冲的 `pushed` 引出来** ＋ ⭐ 一条集成级判据 ✅ |
| 5 | ⚠️ **"开始播放"由谁发起** | ⭐ 清单 §五 问题 1（⭐ 它说是"协议层最大的洞"）⇒ ⭐ **现在已可用**：⭐ `play_seq.pos_reset_i` 接 `met_start`（**按 S2 归零**）⇒ ⭐ 工作流 =「**先按 S2 ⇒ 再灌谱**」✅ 若要 PC/ESP32 远程起播 ⇒ ⭐ 需加一条命令（⭐ ESP32 侧已有 `S`/`X`/`R` 可复用 ✅） |

📌 ⭐ **ESP32 侧就绪度（⭐ 它自己的 `README.md` §〇之二）**：⭐ 定位 = "无线 USB 线"（⭐ 透明转发、⭐ 不看内容 ✅）· ⭐ 波特率 500000 同档 ✅ · ⭐ **反向通路已验收**（2000 字节 round-trip 逐字节一致 ✅）· ⭐ 上行环形缓冲 160 KB ＋ "蓄水/放水" ✅ · ⭐ 串口起播触发 `S`/`X`/`R` 已实现 ✅
⇒ ⭐ **所以 1~5 做完，端到端就通** ✅
