hokuu1102/Gowin2026-PolySynth/sim/evidence/p1-03-20261011/README.md

# `P1-03`：审查的**前提被实测推翻**，⭐ 但修法补上了一个**更窄的真缺口**（2026-10-11）

> ⭐ 这是 `review/时序与逻辑审查-20261009.md` §一 `[P1-03]` 的处置记录 ✅
> ⭐ **结论有两半**：⭐ ① 审查的**量化前提是错的** ✅ ② ⭐ 它的**修法确实有价值**（⭐ 但守的是另一件事 ✅）

---

## 一、⭐ 审查原文的前提

> *"`sample_tick_i` 只要是**电平**（**连续 2 拍以上为高**），
> 每个高拍都会把 `cnt` 清 0 ⇒ `cnt` 永远到不了 `CNT_STOP = 32`
> ⇒ **32 路包络永久冻结** ⇒ **无声**"*

⭐ 修法：⭐ `end else if (sample_tick_i)` → `end else if (sample_tick_i && !running)` ✅
⭐ 它给的用例：⭐ *"`sample_tick` 连续 2 拍为高，然后等 40 拍，断言 `env0 === 16_384`"* ✅

---

## 二、🔴 实测：⭐ **"2 拍就会冻结"【不成立】**

⭐ 我在 `tb/w3b/tb_envelope_bank.sv` 写了 **`P1-03` 差分判据** ✅：

```
① 单拍 tick × 3 轮  ⇒ e_one
② 2 拍 tick × 3 轮  ⇒ e_two
⭐ 判据：e_two === e_one（⭐ 且 e_one != 0 ⇒ 非空洞 ✅）
```

🔴 **实测（⭐ 未修复的 RTL）**：⭐ **判据就绿了** ✅

```text
  ok  : P1-03 a 2-cycle sample_tick == a 1-cycle one (env0=32768)
```

⭐ **为什么**（⭐ 逐行读 RTL ✅）：

```verilog
end else if (sample_tick_i) begin     // ⭐ 高电平期间：每拍清 cnt
    cnt     <= 0;
    running <= 1'b1;
end else if (running) begin           // ⭐ 【一拉低】⇒ 立刻接管
    ...
```

⇒ ⭐ `sample_tick_i` **一拉低**，⭐ `else if (running)` 分支**立刻接管** ✅
⇒ ⭐ 轮转**只是被推迟 1 拍**，⛔ **不会冻结** ✅
⇒ 🔴 **所以"连续 2 拍"这个量化是错的** —— ⚠️ 照审查给的用例**根本复现不出来** ✅

📌 ⭐ **这已经是本项目第 N 次"审查的量化数字不准"** ✅
（⭐ 与 `P2-37` 的"≈1000 LUT4"、⭐ `P1-03` 自己的"2 拍"同族 ✅）
⇒ ⭐ **纪律再次被验证**：⭐ **判据要在动手之前定，⭐ 而且要按【实测】下结论** ✅

---

## 三、✅ 但确实有一个**更窄的真缺口**：⭐ **持续为高**

⭐ 我加了 **`P1-03b`** ✅：⭐ 让 `sample_tick` **全程保持为高**（⭐ 200 拍 ⛔ 一次都不拉低 ✅），
⭐ 并在**仍然为高**的那一拍读 `env0` ✅：

```text
FAIL: P1-03b a PERSISTENTLY-HIGH sample_tick freezes the round-robin (env0 stayed 0)
```

⇒ 🔴 **确认**：⭐ `sample_tick_i` **永不拉低**时，⭐ `cnt` 每拍被清 0、
⭐ `running` 分支**永远轮不到** ⇒ ⭐ **32 路包络永久冻结**（⭐ `env0` 一直是 **0** ✅）✅

### ⚠️ ⭐ 这里也踩了一个坑（⭐ 值得记）

🔴 **第一版 `P1-03b` 假绿**：⭐ 我用 `tick_n(200)`（⭐ 一个**总会释放** tick 的任务 ✅）
⇒ ⭐ 它释放后的 **8 拍低电平**里，⭐ 轮转**就跑完了** ⇒ ⚠️ 判据**通过** ✅

✅ **修法**：⭐ **测"卡住"就不许给它任何低电平的机会** ——
⭐ 直接 `sample_tick = 1;` 然后 `repeat (200) @(negedge clk);` 再读 ✅

📌 ⭐ **教训**：⭐ **"多拍"与"卡住"是两件事** ✅ ——
⭐ 前者只是**推迟**（⭐ 无害 ✅），⭐ 后者才会**冻结**（⭐ 有害 ✅）

---

## 四、🔴 修法试过 ⇒ **打破了真实契约 ⇒ 回退**（⭐ 本轮最终结论）

⭐ 我按审查给的 1 行改了 ✅：

```verilog
- end else if (sample_tick_i) begin
+ end else if (sample_tick_i && !running) begin
```

### ✅ `P1-03b` 确实转绿了

```text
  ok  : P1-03b a persistently-high sample_tick does NOT freeze the bank (env0=32640)
```

### 🔴 但**全量回归 136 / 137** —— ⭐ **`tb_note_manager_sus` 红了** ✅

```text
FAIL: tb_note_manager_sus — 17 pass / 2 fail
  FAIL: S1c no-pedal release => level back to 0 (note gone)
  FAIL: S1d no-pedal release => env inactive
```

⭐ **它是什么**：⭐ `tb/w3b/tb_note_manager_sus.sv` **确实例化了真 `envelope_bank`**
（⭐ `:143`，⭐ 文件头写着 *"本 tb 用真 `envelope_bank` 观察'音有没有消失'"* ✅）
⇒ ⭐ 它是**延音踏板语义的契约** ✅（⭐ HEAD 里是 **19/19 全绿** ✅）

### 🔴 根因：⭐ 它用的 `sample_tick` **比一轮（33 拍）更快**

⭐ 我的改动把语义从"**tick 到来就重开一轮**"改成"**轮转进行中忽略 tick**" ✅
⇒ ⭐ 那个 tb 的 tick 速率下，⭐ 包络的推进**被推迟** ⇒ ⭐ `S1c`/`S1d`（⭐ 释放 ⇒ 音消失）**时序对不上** ✅

### ⚖️ 权衡（⭐ 为什么回退）

| ⭐ 项 | ⭐ 值 |
|---|---|
| ⭐ **收益** | ⭐ **防御性** —— ⭐ 只在"`sample_tick` 卡住为高"时有用 ✅<br>⚠️ 而交付路径上**两者逐位等价**（⭐ 论证见 §五 ✅） |
| 🔴 **代价** | ⭐ **打破一个真实的验收契约**（⭐ `tb_note_manager_sus` 的 tick 速率 ✅） |
| ⇒ | ⭐ **为一个防御性收益去改真实契约，⛔ 不值得** ⇒ ⭐ **回退** ✅ |

✅ **回退后**：⭐ `tb_note_manager_sus` **恢复 19/19** ✅ · ⭐ `tb_envelope_bank` **全绿** ✅

### ⭐ 处置

| ⭐ 项 | ⭐ 状态 |
|---|---|
| ⭐ `rtl/w3b/envelope_bank.v` | ✅ **回退**（⭐ 一行没改 ✅） |
| ⭐ `P1-03`（⭐ 2 拍等价） | ✅ **保留为常驻判据** —— ⭐ 守"**多拍 tick ⛔ 不许改变结果**" ✅ |
| ⭐ `P1-03b`（⭐ 持续为高） | ⚠️ **故意不做成判据**（⭐ 修法不落地 ⇒ ⭐ 做成判据只会留一条永久红 ✅）<br>📌 ⭐ 已写进 tb 注释 ＋ 本文档 ✅ |

---

## 五、⭐ **对交付【零影响】**（⭐ 逐条论证）

| # | ⭐ 事实 | ⭐ 出处 |
|---|---|---|
| 1 | ⭐ `clk_gen` 给的是**单拍脉冲** | ⭐ `clk_gen.v:104` `tick_audio <= (cnt == {CW{1'b0}});` ✅ |
| 2 | ⭐ 帧间隔 = `CLK_PER_SAMPLE = 1024` 拍 | ⭐ `top.v:788` ✅ |
| 3 | ⭐ 一轮 = `CNT_STOP + 1 = 33` 拍 | ⭐ `envelope_bank.v:59` `CNT_STOP = POLY_TARGET = 32` ✅ |
| ⇒ | ⭐ **tick 到来时 `running` 必然是 0** ⇒ ⭐ **新旧写法逐位等价** ✅ | ✅ |

📌 ⭐ 所以**这条修复在交付上"做了也看不出"** —— ⭐ 这正是它**不值得**去动契约的原因 ✅

---

## 六、⚠️ 诚实标注

1. ⭐ **审查的标题（"对多拍 tick 免疫"）方向是对的** ✅ —— ⚠️ 但它的**量化（2 拍）**和
   **用例**都错了 ⇒ ⭐ **照它写会得到一个永远绿的假判据** ✅
   📌 ⭐ 本轮的 `P1-03`（⭐ 2 拍等价 ✅）**保留为常驻判据** ——
   ⭐ 它守的是"**多拍 tick ⛔ 不许改变结果**"这条不变量 ✅
   （⭐ 若有人把 RTL 改成"多拍就冻"⇒ ⭐ 它会红 ✅）
2. ⭐ **`P1-03b` 才是真正能红的那个** ✅（⭐ 修前红、⭐ 修后绿 ✅）
3. ⭐ **交付路径上两者行为完全相同** ✅（⭐ 论证见 §五 ✅）
   ⇒ ⭐ 所以这条修复的**实际价值 = 鲁棒性**（⭐ "tick 卡住"时不会永久无声 ✅），
   ⛔ **不是**修一个正在发作的 bug ✅
4. ⭐ 另一处 `sample_tick_i` 分支（⭐ `envelope_bank.v:140`）**不需要改** ✅ ——
   ⭐ 它是**纯采样锁存**（⭐ 无 `running` 概念 ⇒ ⭐ 卡住也不会冻 ✅）
