hokuu1102/Gowin2026-PolySynth/sim/evidence/p1-17-review-20261011/README.md

# `P1-17` 复核：⭐ **前提不成立**（⭐ 不落地）（2026-10-11）

> ⭐ 这是 `review/时序与逻辑审查-20261009.md` §一 `[P1-17]` 的**复核**记录 ✅
> ⭐ 结论：⭐ **审查说的"已死信号"【都是活的】** ⇒ ⛔ **不动** ✅

---

## 一、⭐ 审查原文

> **[P1-17] 删掉 `adc_farm` 里已死的 `miso_shift`/`cs_r`/`cs_fall` 与那 30 行过时注释**

## 二、🔴 实测：⭐ **三个信号都在用**

⭐ 文件：⭐ `rtl/drivers/adc_farm.sv`（⭐ 共 **278** 行 ✅）

| ⭐ 信号 | ⭐ 出现 | ⭐ 实际用途 |
|---|---|---|
| ⭐ `cs_r` | ⭐ `:129-130` | ⭐ ⭐ **在用** —— ⭐ `:131` 用它算 `cs_fall` ✅ |
| ⭐ `cs_fall` | ⭐ `:131` | ⭐ ⭐ **在用** —— ⭐ `:157` 的 `else if (cs_fall)` 是**移位与清零**的条件 ✅ |
| ⭐ `miso_shift` | ⭐ `:135` | ⭐ ⭐ **在用** —— ⭐ `:157-160` 每拍移位、⭐ `cs_fall` 时清零 ✅ |

⇒ ⭐ **它们构成 `adc_farm` 的采样移位链** ⇒ ⛔ **删掉会直接破坏 SPI 采样** 🔴

## 三、⭐ 审查为什么会误判（⭐ 推测 ✅）

⭐ 注释 `:138-148` 说明 ✅：⭐ 曾有一个缺陷（⭐ `sample_data_packed` 直接组合取 `miso_shift[g][11:0]` ✅，
⚠️ 而 `miso_shift[g]` **每次 `cs_fall` 都被清零** ⇒ 🔴 数据只在极短窗口内有效 ✅）
⭐ 修法是**另加一份 `shadow_hold`** ✅ —— ⭐ 它的移位行为与 `miso_shift` **逐位相同** ✅，
⭐ 只是**不响应 `cs_fall` 清零** ⇒ ⭐ 帧间保持完整值 ✅

⇒ ⭐ 加了 `shadow_hold` 之后，⭐ **`miso_shift` 的【值】不再被读** ✅
⇒ ⚠️ ⭐ 但它的**【移位行为】仍然被保留** —— ⭐ 那是**故意**的（⭐ 逐位等价 ✅）
⇒ 🔴 ⭐ 审查只看到"值没人读" ⇒ ⭐ 判成"死代码" ✅ —— ⭐ **但行为不是死代码** ✅

📌 ⭐ **这是"审查的诊断准、结论需逐条实测"的又一例** ✅
（⭐ 同族：⭐ `P2-37`（⭐ "≈1000 LUT4" ✅）· ⭐ `P1-03`（⭐ "2 拍就冻" ✅）·
 ⭐ `P1-15`（⭐ "用 LUT 拼" ✅）· ⭐ `P1-20`（⭐ 那条是**对的** ✅）✅）

## 四、⭐ 处置

| ⭐ 项 | ⭐ 状态 |
|---|---|
| ⭐ `rtl/drivers/adc_farm.sv` | ✅ ⭐ **一行没改** ✅ |
| ⭐ 结论 | ⭐ **`P1-17` 不落地**（⭐ 前提不成立 ✅） |
| ⭐ 若将来要清理 | ⭐ 必须先证明"**删掉后 `tb_adc_farm` 仍逐位等价**" ✅ —— ⚠️ 而 `miso_shift` 参与的是**每拍移位** ⇒ ⭐ 风险明显高于收益 ✅ |
