hokuu1102/Gowin2026-PolySynth/sim/evidence/score-scale-20261011/README.md

# 🔴 曲谱音高的 **1024 倍量纲错**（2026-10-11 发现并修复）

> ⭐ 本轮在**给"录制回传"写导出格式**时**顺带发现**的 —— ⚠️ 它比原定任务**重要得多** ✅
> ⭐ 因为：🔴 **不修它，整条曲谱链路"灌了谱也听不到正常音高"** ✅

---

## 〇、一句话

> 🔴 **曲谱的 `inc` 是"50 MHz 口径"，而 `oscillator_bank` 的相位是"采样率口径"**
> ⇒ ⭐ **音高低 1024 倍（正好 10 个八度）** ⇒ 🔴 **整条曲谱变成次声波（0.43 Hz）** ✅

---

## 一、⭐ 证据链（⭐ 每一环都有 `file:line`）

| # | ⭐ 事实 | ⭐ 出处 |
|---|---|---|
| 1 | ⭐ PC 侧工具按 **50 MHz** 算音高增量 | ⭐ `tools/mid2evt.py:115` **`FS = 50_000_000.0`** ✅<br>⭐ `:284-286` `note_to_phase_inc(midi) = round(f × 2^32 / FS)` ✅ |
| 2 | ⭐ 它给 **MIDI 69（A4 = 440 Hz）** 写 **`inc = 37791`** | ⭐ `440 × 2^32 / 50e6 = 37790.9` ✅ |
| 3 | ⭐ 它自己**核对过量程**：MIDI 127 → `1077509` | ⭐ `:133` *"`INC_MAX = 2097151 > MIDI 127 (1077509), with headroom"* ✅ |
| 4 | 🔴 FPGA 侧**直接零扩展** | ⭐ `top.v:3965`（⭐ 原文）`wire [31:0] ps_evt_inc = {11'd0, ps_note_data[43:23]};` ✅ |
| 5 | ⭐ 而 `oscillator_bank` 的相位**按 `sample_tick_i` 推进** | ⭐ `oscillator_bank.v:725` `phase_q <= phase_q + lane_inc`<br>⭐ 在 `:650` 的 `else if (sample_tick_i)` 门控内 ✅ |
| 6 | ⭐ 采样率 = **48.828125 kHz** | ⭐ `top.v:788` `.CLK_PER_SAMPLE (1024)` ⇒ `50e6 ÷ 1024` ✅ |
| 7 | ⭐ **实时弹的音高是对的**（⭐ 交叉验证） | ⭐ `rtl/w3a/axis_map.v:48` `BASE_INC = 32'h0010_0000`<br>⭐ `key_inc(k) = BASE_INC × 2^(k/12)`（⭐ `:195`）<br>⇒ ⭐ 键 69 ≈ **5.6e7** ⇒ ⭐ `5.6e7/2^32 × 48828 ≈ **641 Hz**` ✅（⭐ 量级正确 ✅） |
| 8 | ⭐ 曲谱路径上**没有任何补偿移位** | ⭐ `grep '<< *10\|1024'` 在 `top.v`/`seq_arb.v`/`play_seq.v` ⇒ ⭐ 只有 `CLK_PER_SAMPLE` 与容量，⛔ 无音高缩放 ✅ |

### ⭐ 算式（⭐ 一句话）

```
PC 写   inc = f × 2^32 / 50e6            （⭐ f = 440 ⇒ 37791 ✅）
FPGA 用 inc 当"每采样拍的相位增量"        （⭐ 采样率 48828.125 Hz ✅）
⇒ 实际频率 = 37791 / 2^32 × 48828.125 = 0.43 Hz        🔴
⇒ 比值 = 50e6 / 48828.125 = 1024 = 2^10               🔴 低 10 个八度
```

---

## 二、⭐ 为什么一直没暴露（⭐ 这条很重要）

🔴 **因为这条链路在 2026-10-11 之前【结构上不可能工作】** ✅

| # | ⭐ 原因 | ⭐ 出处 |
|---|---|---|
| 1 | ⭐ `play_seq` **从未被例化**（⭐ 缺事件缓冲 ⇒ 读侧无源 ✅） | ⭐ 2026-10-11 的 `U-19` 才补上 ✅ |
| 2 | ⭐ `P0-02` 门控把曲谱**载荷的 8 个字节全挡掉** | ⭐ 2026-10-11 修 ✅ |

⇒ ⭐ **两处都修好之后**，⭐ 这条 1024 倍的量纲错**才会第一次被听到** ✅
📌 ⭐ **它差点在"第一次上板灌谱"时爆出来** —— ⭐ 而那时的症状会是
"**灌了谱，灯亮了，但没声音**"（⭐ 0.43 Hz 在人耳外，⭐ 只会听到包络的咔哒 ✅）
⚠️ ⭐ 那会**非常难查**（⭐ 因为"灯亮了"会让人以为链路是通的 ✅）

---

## 三、⭐ 契约的洞（⭐ 根因）

⭐ `files/20-代码/play_seq接口冻结契约.md` **只定义了 `tick_inc` 的量纲** ✅：

| 字段 | ⭐ 契约里的量纲 | ⭐ 对不对 |
|---|---|---|
| ⭐ `inc`（**`kind=2`** ⇒ `tick_inc`） | ⭐ `:149` `tick_inc = round(2^32 × f_tick / 50e6)` ✅ | ✅ **对** —— ⭐ 因为 `beat_gen` 的相位**按系统时钟**推进 ✅ |
| 🔴 `inc`（**`kind=0/1`** ⇒ `phase_inc`） | 🔴 **契约里没有公式** ✅ | 🔴 **没有定义** ⇒ ⭐ 漏洞就在这里 ✅ |

📌 ⭐ 而 `:141-143` 的"**最易错点**"只提醒了"**同一个字段两种语义**"，
⚠️ **没有提醒"两种语义还对应两个不同的时钟口径"** ✅
📌 ⭐ `:165` 还记着 *"本表初版曾算错 1000 倍（误按 `2^32×f/FS` 直接取整而混淆了量纲）"*
⇒ ⭐ **说明量纲这件事在这个项目里反复咬人** ✅

---

## 四、✅ 修法（⭐ 一行 ＋ 判据）

```verilog
//  top.v —— ⭐ **只移【音高】那条路** ✅
- wire [31:0] ps_evt_inc = {11'd0, ps_note_data[43:23]};
+ wire [31:0] ps_evt_inc = {1'b0, ps_note_data[43:23], 10'b0};   // ⭐ ×1024
```

### ⭐ 为什么是"FPGA 侧左移 10 位"（⭐ 而不是改 PC 侧）

| ⭐ 方案 | ⭐ 结果 |
|---|---|
| ⭐ **A：FPGA 左移 10 位** | ✅ **可行** —— ⭐ 线上 21 位 ⇒ 移后 **31 位有效** ✅ 相对误差 ≤ `2^-21`（⭐ ≈ **0.0008 音分**）✅ |
| 🔴 B：`mid2evt` 直接用采样率算 | 🔴 **不可行** —— ⭐ MIDI 127 要 `1.1e9` ⇒ **31 位装不进 21 位字段** ✅ |

⇒ ⭐ **只有 A 可行** ⇒ ⭐ 这也**反证了 21 位字段本来就是为"50 MHz 口径"选的** ✅

### ⛔ **关键边界：⛔ 只能移音高，不许移速度**

⚠️ `kind=2` 的 `inc` 是 **`tick_inc`**（⭐ 走 `play_seq.tick_inc_o` → `beat_gen` ✅）
⇒ ⭐ **它的量纲本来就是对的**（⭐ `beat_gen` 按**系统时钟** ✅）
⇒ ⛔ **移了节拍就会快 1024 倍** 🔴
📌 ⭐ 判据：⭐ `tb_top_score_path` 的 **`Fa`~`Fd`**（⭐ `tick_inc_o` 必须**仍等于原值** ✅）

---

## 五、⭐⭐ 判据（⭐ 先出"未修复能红" ✅）

⭐ 在 `tb/w3b/tb_top_score_path.sv` 新增 **H 段** ✅

| # | ⭐ 判据 |
|---|---|
| ⭐ `H1` | ⭐ 把 `ps_evt_inc` **按采样率**换算成 Hz ⇒ ⭐ **必须是 440 Hz**（⭐ 容差 ±1 Hz ✅） |
| ⭐ `H2` | ⭐ **非空洞性**：⭐ 该值必须**超过 21 位字段的上限**（⭐ 证明真的被放大过 ✅） |

⭐ **判据设计的关键**：⭐ `H1` **把"量纲"变成了"频率"** ✅
⇒ ⭐ 它**同时**抓住"**没移位**"与"**移错位数**"两种错 ✅
（⭐ 未修时 `37791` 换算出来是 **0 Hz** ⇒ ⭐ **必红** ✅）

### ⭐ 实测

```text
🔴 未修复：FAIL: H1 the score note's phase_inc yields 440 Hz at the SAMPLE rate (not 50 MHz)
           FAIL: H2 non-vacuity: the value must have been SCALED up past the 21-bit wire field
           FAIL: tb_top_score_path - 18 pass / 2 fail
✅ 修复后：ok  : H1 ... / ok  : H2 ...
           ok  : Fa tick_inc_o now carries the tempo from the kind=2 event   ← ⭐ 速度路径未被牵连 ✅
           PASS: tb_top_score_path - 20/20 judgements held
```

---

## 六、⚠️ 诚实标注

1. ⭐ **本条是【顺带发现】的** —— ⭐ 本轮原定任务是"录制回传的导出格式"，
   ⚠️ 而我在**核对 `inc` 字段该给多少位**时撞上了它 ✅
   📌 ⭐ 这正说明"**动手前先把量纲算清**"的价值 ✅
2. ⭐ **还没上板**（⭐ 本轮是仿真验证 ✅）
   ⇒ ⭐ 上板要听：⭐ **灌一段真实曲谱 ⇒ 音高对不对**（⭐ 这是**第一次**可能听到 ✅）
3. ⚠️ ⭐ **`mid2evt.py` 侧的注释没改** —— ⭐ 它的 `FS = 50e6` **本身没错**
   （⭐ 那是"线上格式"的口径 ✅）⇒ ⚠️ 但**建议补一句**"⭐ FPGA 侧会左移 10 位" ✅
   📌 ⭐ 本轮**没改 PC 侧**（⭐ 那是 ESP32/PC 线的文件 ✅）
4. ⚠️ ⭐ **`play_seq接口冻结契约.md` 的洞没补** —— ⭐ 建议补上
   `phase_inc = (2^32 × f / 50e6) << 10`（⭐ 即"线上 21 位 ⇒ 采样率口径" ✅）
   📌 ⭐ 本轮**没改契约文档**（⭐ 它属于 `files/` 的设计文档线 ✅）—— ⭐ 记入待办 ✅
5. ⭐ **`kind=1`（`note_off`）的 `inc` 也会被移** —— ⚠️ 但 `note_off` 的 `inc` **不被使用**
   （⭐ 它只关音 ✅）⇒ ⭐ **无影响** ✅
6. ⭐ **`kind=2` 已验证不受影响**（⭐ `Fa`~`Fd` ✅）
