hokuu1102/Gowin2026-PolySynth/sim/evidence/led-indicator-20261003/README.md

# 证据 · WS2812 指示层（第 2 层）落地（2026-10-04）

> **实验名**：`led-indicator-20261003`
> **分支**：`timing/converge-h5-20261003` · **基线**：`f0f0ec1`（ADSR 共享 + WS2812 PHY 已落地）
> **目的**：⭐ 把 WS2812 的**第 2 层（指示层）**做出来 —— 状态码 → 颜色/闪烁，
> 驱动控制板灯带的 **LED0..LED6**（⭐ 用户给定的 7 路语义）。
> **规格**：`files/20-代码/WS2812指示层规格-20261003.md`（⭐ §七 是本次的落地记录）

---

## 1. ⭐ 改了什么（⭐ 一次只改一个变量：就是"加指示层"这一件事）

| 文件 | 动作 | 说明 |
|---|---|---|
| `rtl/w3a/led_indicator.v` | ⭐ **新增** | 指示层：表驱动（状态码 → 颜色）＋ 共享快闪计数器 ＋ 拍点闪拉伸 |
| `tb/w3a/tb_led_indicator.sv` | ⭐ **新增** | 验收 tb（⭐ 7 路语义 + 闪烁周期 + 拍点闪时长；⭐ 两个 DUT 实例：生产参数 / 小参数） |
| `rtl/top.v` | 改 | ① 三根**跨 generate** 状态线（`led_beat`/`led_gear_st`/`led_looper_st`）② 例化 `u_led_indicator` ③ 用 `case` 把 7 路颜色接到灯带写口（⭐ 替换掉原来的"上电自检图案"常量）④ `u_fader_gear.gear_o` 首次接出 |
| `Gowin2026.gprj` | 改 | ⭐ 登记 `rtl/w3a/led_indicator.v`（⛔ 不登记会被综合**静默丢弃**） |

⭐ **未改**：`ws2812_driver.v`（第 3 层 PHY）· `constr/`（引脚表）· 任何 tb 的既有判据。
⛔ **未碰**：`files/10-硬件/`。

### 1.1 ⭐ 接线要点（⭐ 三条容易被"看起来对"骗过去的地方）

1. **跨 generate 的三根线必须由两个互斥分支各自驱动**（⭐ 与 `led_blink` 同一手法）：
   `g_sound` 给真值、`g_silent` 显式给 0 ⇒ ⛔ 否则静音档悬空成 `x`。
2. **鼓机"开"的算式必须与 `g_sound.src_b_valid` 逐项一致**
   （`SEL_DRUM==1 && METRONOME_ON!=0 && met_on_r`）⇒ ⭐ 否则指示灯会说"鼓机在响"而实际不响。
3. **looper 三态用 `loop_rec_on_r`/`loop_play_on_r`**，⛔ 不用 `looper.layer_state_o`
   （⭐ 后者只有 1 位，分不出"录"和"放"）。

---

## 2. ⭐ 四道门

| 门 | 判据 | 结果 | 证据文件 |
|---|---|---|---|
| **① 综合门** | `ERROR=0`（⭐ 看日志 `GowinSynthesis finish`） | ✅ 退出码 0 | `syn-led-indicator.log` |
| **② 聚焦 tb** | 全 PASS | ✅ `tb_led_indicator` / `tb_ws2812_driver` / `tb_top_m0` / `tb_test_mode_top` 各 **通过 1 / 共 1** | `sim/evidence/tb_led_indicator.log` 等 |
| **③ 干净 PnR** | 出 `.fs` ＋ **无 `PR0004`** ＋ `0 setup / 0 hold` | ✅ **7.1 min** · `.fs new=True` · **0/0** · `Fmax 52.039 MHz`（≥51.5） | `pnr-led-indicator.log` · `timing.txt` · `Gowin2026-led-indicator.fs` |
| **④ 全量回归** | **通过数 == 共数** | ✅ ⭐ **通过 119 / 共 119**（⭐ 基线 118 ＋ 本轮新增 `tb_led_indicator` = 119；⭐ 另 2 个工具 tb 按既有规则跳过） | `regression-full.log` |

⭐ **位流**：`Gowin2026-led-indicator.fs`（18,829,983 B）
⭐ **sha256**：`FBBEDD73594A1B9FE5ACE17B687FBB664E29104C8C9ECF81FA780DA273A04725`
⚠️ `PR1014`（`clk_d` 走通用布线）是**既有告警**（`K-45`），⛔ 与本次改动无关。

---

## 3. ⭐ 资源对照（⭐ 顶层 `T_*` 差值口径 —— ⛔ 别看子模块行，见 `T7`）

| 项 | 基线（ADSR 共享后） | 加指示层后 | 增量 |
|---|---|---|---|
| `T_Lut` | 31672 | **31763** | ⭐ **+91** |
| `T_Register`（FF） | 16199 | **16402** | **+203** |
| `T_Alu` | 7906 | **7929** | +23 |
| `MULTALU27X18`（DSP） | 7 | 7 | **0** |
| `T_Bsram` | 30 | 30 | **0** |

- `rsc-before-adsr-baseline.xml` = 基线（⭐ 从 `p5-adsr-20261003/syn_after2_rsc.xml` 复制）
- `rsc-after.xml` = 本次（⭐ 干净综合：`gowin_build.ps1` 先清 `impl/gwsynthesis`）

🔴 **T7 提醒**：`rsc-after.xml` 里 `u_led_indicator` 只报 `52 LUT / 66 FF` ——
⭐ 那是**全局优化搬走**后的假象（⭐ `u_ws2812` 同期从 ~138 涨到 201 LUT）
⇒ ⭐ **只有顶层差值可信** ✅

---

## 4. ⭐⭐ 能红判据（⭐ 两次真变异，⭐ 都实测变红）

| 变异 | 改法（⭐ 只改 RTL，⛔ 不改 tb） | 结果 | 日志 |
|---|---|---|---|
| **M1** | 音色 `2'd1`：`C_CYAN` → `C_VIOLET` | 🔴 `(1b)` + `(2a)` **红**（2 条） | `mut-M1-timbre-cyan-to-violet.log` |
| **M2** | 输出级去掉快闪门控：`&& fast_off` → `&& 1'b0` | 🔴 `(7c)` + `(7d)` + `(7f)` **红**（3 条） | `mut-M2-no-fast-gating.log` |

⭐ **还原核对**：变异前后 `rtl/w3a/led_indicator.v` 的
`sha256 = F60ADC7BF741446078FACDAFC1631A90115443DF1724958526366C84BC145C65` **逐字节一致** ✅
（⭐ 备份在 `build/mutation/led_ind/`，⭐ 字节副本见 `led_indicator.v.orig`）

### 4.1 ⭐ tb 里两条"踩过才写进去"的教训

1. 🔴 **拍点闪拉伸会跨测试段存活**：生产实例的拉伸是 **100 ms**，
   ⇒ ⚠️ "节拍器开但还没拍点 ⇒ 灭"这条判据**只能放在第一个拍点之前**做，
   ⛔ 放在后面必**假红**（⭐ 第一版就栽在这）。
2. 🔴 **快闪周期⛔ 不能用 `(末沿−首沿)/(边数−1)` 量**：⭐ 那会把窗口首尾的**半个周期**平均进去
   （⭐ 实测量出 974 而不是 1024）⇒ ⭐ 改成**相邻上升沿间隔的 min/max**（⭐ 实测 `[1024..1024]`）✅

---

## 5. ⚠️ 已知限制 / 待办

| # | 项 | 说明 |
|---|---|---|
| 1 | ⚠️ **鼓机与节拍器的指示灯同亮同灭** | ⭐ 因为它们共用 `met_on_r`（⭐ 硬件事实）⇒ 要独立开关得**新增一个运行时寄存器**（⭐ 另一个变量，本次不做） |
| 2 | ⚠️ **gear 2/3（摇把/无）是预留行** | `fader_gear` 今天只在 0/1 间切 ⇒ led5 实际只在 **紫 ↔ 青** 之间变 |
| 3 | ⚠️ **亮度是满 8 位** | 7 颗全亮约 **420 mA @5 V**；⭐ 调暗只需改颜色表字面量 |
| 4 | ⚠️ **未上板** | ⭐ 本次验证 = 仿真 + 综合 + PnR，⛔ **没有上板波形** |
| 5 | ⚠️ **`ctrl_ws_o` 3.3 V 直驱 5 V 灯带** | ⭐ WS2812B `VIH = 0.7×VDD = 3.5 V` ⇒ **3.3 V 临界**，⭐ 建议加电平转换（⭐ 属画板线） |
