hokuu1102/Gowin2026-PolySynth/sim/evidence/top-led-strip-20261004/README.md

# 证据 · top 级灯带集成验收（`ctrl_ws_o` 位流解码）（2026-10-04）

> **实验名**：`top-led-strip-20261004`
> **分支**：`timing/converge-h5-20261003` · **起点**：`94a1e2a`（指示层已落地）
> **目的**：⭐ 堵上一个**口径缺口** —— `tb_led_indicator` 只测**指示层模块本身**、
> `tb_ws2812_driver` 只测**PHY 位时序**，⛔ **全仓没有任何 tb 观察 `ctrl_ws_o`**
> ⇒ `top.v` 里"7 路颜色 → 写口 `case` → 驱动"这段接线**当时没有判据**：
> ⚠️ 切片顺序写错 / 灯序颠倒 / `WS_LED_N` 差一 ⇒ **119 个 tb 全都会绿**。

---

## 1. ⭐ 改了什么（两个变量，但属**同一件事**：让"灯带显示对不对"可判）

| 文件 | 动作 | 说明 |
|---|---|---|
| `tb/top/tb_top_led_strip.sv` | ⭐ **新增** | 把 `ctrl_ws_o` 的 **384 个 bit cell 解回 GRB → 24 位颜色**，逐颗比对（⭐ **只看引脚波形**，⛔ 不引用任何 DUT 内部信号） |
| `rtl/top.v` | 改 **1 行**（`g_silent` 档） | 🔴 `led_gear_st` 由 `2'd0` 改成 `2'd3` —— ⭐ **新 tb 第一跑就抓到的语义缺陷**（见 §3） |

⭐ **未改**：`led_indicator.v` · `ws2812_driver.v` · `constr/` · 任何既有 tb 的判据。
⛔ **未碰**：`files/10-硬件/`。

### 1.1 ⭐ 判据（6 条，⛔ 全部只看端口波形）

| # | 判据 | 为什么它能红 |
|---|---|---|
| 1 | 上电帧 `LED0..LED6` == 期望表（白/灭/灭/灭/暗蓝/青/绿）＋ ⭐ **`LED7..LED15` 全灭** | ⭐ 同时钉住**切片顺序**、**灯序**、写口 `default` |
| 2 | ⭐ **活体**：往 `uart_rx` 发裸 `'I'`（切音色）⇒ **下一帧 LED0 变青**，⭐ 且**只有 LED0 变** | ⛔ 证明不是常量、⛔ 不是串线 |
| 3 | ⭐ **跨 generate 分支**：`DEMO_CHORD_ON=0`（`g_silent`）实例 ⇒ **LED5 必须灭** | ⭐ 钉住"两根跨分支状态线各自驱动" |
| 4 | 整帧 = **384 × 62 拍** ＋ 帧间长低 ≥ 10000 拍 | ⭐ 位周期/帧间复位契约 |
| 5 | `ws_strip_o` 恒 `3'b000` · `esp_uart_tx_o` 恒高 | ⭐ 预留脚**没被这次改动碰** |
| 6 | A8：`ctrl_ws_o` 复位后无 X/Z | — |

---

## 2. ⭐ 四道门

| 门 | 判据 | 结果 | 证据 |
|---|---|---|---|
| **① 综合门** | `ERROR=0`（⭐ `GowinSynthesis finish`） | ✅ **0 行 ERROR** | `syn-Gowin2026.log` |
| **② 聚焦 tb** | 全 PASS | ✅ **4/4**：`tb_top_led_strip` / `tb_led_indicator` / `tb_ws2812_driver` / `tb_top_m0`（各 通过 1 / 共 1） | `sim/evidence/tb_top_led_strip.log` 等 |
| **③ 干净 PnR** | 出 `.fs` ＋ **无 `PR0004`** ＋ `0 setup / 0 hold` | ✅ **8.2 min** · `.fs new=True` · **0/0** · `Fmax 52.039 MHz`（≥51.5） | `pnr-led-strip.log` · `timing.txt` |
| **④ 全量回归** | **通过数 == 共数** | ✅ **通过 120 / 共 120**（⭐ 119 ＋ 本轮新增 `tb_top_led_strip`） | `regression-full.log` |

⭐ **位流**：`Gowin2026-led-strip.fs`（18,829,983 B）
⭐ **sha256**：`9511BFDF9FA661B29B923A74C05EAECC509E216984B8A1C8622729EB924B5794`

### 2.1 ⭐⭐ 一个**附带的反证**（⭐ 说明这次 RTL 改动只在静默档）

| 项 | 上一轮（`94a1e2a`） | 本轮 | |
|---|---|---|---|
| `T_Lut` | 31763 | **31763** | 相同 |
| `T_Alu` | 7929 | **7929** | 相同 |
| `T_Register` | 16402 | **16402** | 相同 |
| `MULTALU27X18`（DSP） | 7 | **7** | 相同 |
| `T_Bsram` | 30 | **30** | 相同 |
| `.fs` 字节数 | 18,829,983 | **18,829,983** | 相同 |

⇒ ⭐ **交付档（`DEMO_CHORD_ON=1`）的网表逐项不变** —— ⭐ 因为 `g_silent` 分支
**根本不参与该配置的例化** ⇒ ⚠️ 这同时**反证**了"我只动了静音档"这个判断 ✅
（📌 `.fs` 的 sha256 不同：⭐ 位流文件里含工具写入的头/时间戳 ⇒ ⛔ 不能拿 sha256 当"网表相同"的判据，**字节数 + 资源**才是）

---

## 3. ⭐⭐ 新 tb 第一跑就抓到的东西（⭐ 值得记住）

```
FAIL: (3d) led5 推子 = 灭（g_silent 把 led_gear_st 驱动成 0）[led5] = 8000ff want 000000
```

🔴 **现象**：`g_silent`（静音档）下 `led5` 显示 **紫 `8000FF`**。
🔎 **根因**：⭐ 我原来在 `g_silent` 里写 `assign led_gear_st = 2'd0;`
—— ⚠️ 而指示层的表里 **`2'd0` = "变调"（紫）**，⭐ 可这一档**根本没有推子**
⇒ 🔴 **指示灯在说谎**（⭐ 它会让人以为推子处在变调档）。
✅ **修法**：改成 `2'd3`（= **"无"** ⇒ **灭**）⇒ ⭐ 语义与事实一致 ✅

📌 **同族口径（⭐ 一并定死，写进注释）**：`led_looper_st` 仍是 `2'd0`（空闲 ⇒ 暗蓝）——
⭐ 因为用户的 looper 语义里**没有"无"这一档**（只有 空闲/录音/回放）
⇒ ⭐ "没有 looper" 与 "looper 空闲" 在灯上**本就是同一个状态**（⭐ 也是它的复位态）✅

> ⭐ **教训**：⭐ **"状态码 0 等于什么"必须逐路核对** ——
> `gear` 的 0 是"变调"（有语义！），⛔ 不是"没接"；
> ⭐ 这正是"缺一个集成判据"时**最容易漏掉**的一类错（⭐ 模块级 tb 永远看不到它）。

---

## 4. ⭐⭐ 能红判据（⭐ 两次真变异，⭐ 都实测变红，⭐ RTL 逐字节还原）

| 变异 | 改法（⭐ 只改 `rtl/top.v`） | 结果 | 日志 |
|---|---|---|---|
| **M1** | 写口**切片错位**：`5'd0: ws_wr_data = led_col_flat[24 +: 24];` | 🔴 `(1a)` + `(2a)` + `(3a)` 红 | `mut-M1-slice-offset.log` |
| **M2** | 写口 `default` 点亮：`24'h000000` → `24'hFF0000` | 🔴 `(1h)` + `(2h)` + `(3e)` 红 | `mut-M2-default-lit.log` |

⭐ **还原核对**：变异前后 `rtl/top.v` 的
`sha256 = 621A3F749024A70BC4AAC82B4C2CC0CFDDAF84048B9D3DEFB673ED4F64930873` **逐字节一致** ✅

---

## 5. ⚠️ 已知限制

| # | 项 | 说明 |
|---|---|---|
| 1 | ⚠️ **tb 实测 43 s** | ⭐ 三次 WS2812 帧（每帧 23,808 ＋ 帧间 20,000 拍）⇒ ~13.4 万拍。<br>⚠️ 占默认 120 s 预算的 36% ⇒ ⭐ 若将来并行跑回归出现 `TIMEOUT`，**把它加进 `sim/tb_all.ps1` 的 `$heavyTb`**（300 s 档） |
| 2 | ⚠️ **仍未上板** | ⭐ 灯序的**物理左右**仍要上板确认（⭐ LED0 = **数据输入侧第一颗**） |
| 3 | ⚠️ **只覆盖"上电态 + 切音色"** | ⛔ 节拍器拍点闪 / 鼓机 4 型 / looper 录音快闪**没有**在 top 级覆盖（⭐ 它们由模块级 `tb_led_indicator` 覆盖）⇒ ⭐ 要 top 级覆盖得发 `'B'`/`'D'`/`'R'`，⏳ 可后补 |
