hokuu1102/Gowin2026-PolySynth/evidence/main_verify_20261014/python_requirements.txt

bleak==3.0.2
mido==1.3.3
packaging==26.3
pyserial==3.5
typing_extensions==4.16.0
winrt-runtime==3.2.1
winrt-Windows.Devices.Bluetooth==3.2.1
winrt-Windows.Devices.Bluetooth.Advertisement==3.2.1
winrt-Windows.Devices.Bluetooth.GenericAttributeProfile==3.2.1
winrt-Windows.Devices.Enumeration==3.2.1
winrt-Windows.Devices.Radios==3.2.1
winrt-Windows.Foundation==3.2.1
winrt-Windows.Foundation.Collections==3.2.1
winrt-Windows.Storage.Streams==3.2.1
