hokuu1102/Gowin2026-PolySynth/docs/hmi-checklist-integration-20261102.md

# 串口屏清单配套集成（2026-11-02）

基线为本地鼓机四型循环修复提交 `4c714ee59803fcf3a9c3f1dddb325e5ca30e44d7`，属于51交付线。
本次使用用户提供的串口屏配套RTL清单，不回退至旧612b98da，不修改main或远端。

## RTL改动

- R3：新增 `71 05 <档位> FF FF FF`。0=变调、1=音高颤音、2=音量颤音，严格要求两字节帧体和值0..2；非法值、缺载荷、多载荷不产生选档脉冲。顶层连接到已有的fader_gear直选接口。
- 屏幕实际切到不同档位时，在同一时钟沿锁存离开的档位并更新档位。重复点当前档保持原锁定状态；不自动解锁目标档。优先级保持直选0>1>2>实体/J循环；同拍实际直选切档优先自动锁存，锁定位仍只有一个时序块写入。
- 实体切档键、串口J、屏幕“下一档”继续原有循环规则，需要时用实体锁定键手动锁定。实体锁定键仍只翻转当前档；解锁立即跟随当前推子，不等待拾取。自动锁存限定为清单指定的屏幕直选路径。
- R4：`z_pr`改为真实音高颤音原始速率 `st_prate_i`，并将变化重发触发源从fx_rate切到st_prate，避免只改表达式后运行中不刷新。0/2048/4095对应0/50/99，与j_pr一致；频率文本和实际LFO映射保持原样。现行文本映射原始4095为12.0Hz，清单提及23.1Hz不是当前文本映射，本次不改。
- R5：零移调只显示 `0 SEMI`；正负移调格式不变。移除未使用的原调常量。
- R2：核实既有 `6F <n>` 选参协议，n=0..7。后续FF FF FF不会继续充当参数；屏幕仍建议只发两个字节。大写4F是回传开关，不可混用。
- R1效果器XOR翻转协议已存在，本次保留。鼓机四型循环、三档音效叠加、回传关闭后不再接收新事件、Loop/踏板和主时钟约束均保留。未改变DSP、LFO、推子量化或存储容量。

## 屏工程待配套修改

仓库没有提供 `p0.HMI`，本次不能产出或声称已更新屏幕TFT。以下操作须在原屏工程执行：

1. 三个头部按钮的bco2设为与各自关闭态相同的灰色。失真头部按钮脚本中的52657改为52857。合唱/延迟补开关颜色切换；保留发送 `71 19 01` / `71 19 02` / `71 19 04` 的事件。未提供屏工程，无法验证具体颜色脚本和控件本地变量，禁止盲目重复翻转。
2. 六个参数按钮释放事件分别发送：失真增益 `printh 6F 00`、补偿 `printh 6F 01`；合唱混合 `printh 6F 02`、长度 `printh 6F 07`；延迟反馈 `printh 6F 03`、长度 `printh 6F 06`。不加FF尾。
3. 音高颤音头部发送 `printh 71 05 01 FF FF FF`，音量颤音头部发送 `printh 71 05 02 FF FF FF`。仅切档，不强制增加深度。深度0仍无颤音。

## 上板验收

1. 开机档1，调出音高颤音；点屏音量颤音头部切档2，检查原音高颤音保留。调出音量颤音；屏直选档0，再归零推子，两种颤音仍保留。回档1保持旧值；按实体锁定键解锁后立即跟随当前推子。
2. 连点同一个头部不改变锁定位。深度为零时切档不应自动出现颤音。
3. 在未锁的音高颤音档将速率从零拉满，z_pr与j_pr均由0到99；调FX速率不应改变z_pr。频率文本使用原映射。
4. 零移调显示0 SEMI；正负半音无变化。逐个参数按钮确认EC11改变对应参数。
5. 鼓机持续按切型键应ⅠⅡⅢⅣⅠ循环；B独立启停。回传开关再次关闭后，之前已入队帧可发送完，但后续新事件不再进入发送队列。

仿真与原生时序结果见交付目录中的regression-summary.json、native-result.json及timing-gate.log；实机验收仍需烧录完成。
