hokuu1102/Gowin2026-PolySynth/hmi7/串口屏v2-修订版-20261029.md

# 🖥️ 串口屏 v2 修订版 · TJC X2 7寸 1024×600 搭建清单

> **屏**：淘晶驰 TJC X2，7 寸，1024×600，接 **FPGA 板载 UART**
> **上位机**：USART HMI（TJC 版）
> **源文档**：`串口屏v2.md`（微信传输，2026-10）——本文件在其基础上修订
> **修订日期**：2026-10-29 · 修订人：丙（RTL 侧负责人）
> **配套 RTL**：`rtl/w3c/uart_ui.v`（回显 FSM，22 状态字段 + 心跳，tb 148 checks PASS）

---

## 〇、🔴 本版改了什么（对照 v2 的同类型错误，共 10 处）

| # | 错误类型 | v2 原文 | 本版修正 |
|---|---|---|---|
| 1 | **显示行做成按钮** | `t_base` 类型=按钮、整行触控切换八度 | `t_base` 改**文本**（纯显示），新增小按钮 `b_oct` 叠放在右端承接触控（⭐ 同类规则：**FPGA 回显的行一律文本，触控拆小按钮**） |
| 2 | **过时波特率文字** | `t_conn`="UART 500K [ONLINE]"、`t_fx_uart`="UART 500K 8N1" | 均改 **"115.2K"**（2026-10-28 板载口 500k→115200 改档，FPGA 侧已同步） |
| 3 | **心跳机制描述过时** | p_hb "FPGA 周期脉冲驱动翻转" | 实际机制：**屏侧 tm0 500ms 闪 + tm1 1500ms 看门狗 + FPGA 每秒发 `tm1.tim=1500`**（RTL 已交付）；p_hb 类型明确为**双态按钮**（sta=图片，pic=0 灰 / pic2=1 绿） |
| 4 | **缺失回显控件** | 无 `t1` | FPGA 实际回显 `t1.txt`（Test Mode：关/4/8/16/32）——**屏上必须有叫 `t1` 的文本控件**，否则该帧被丢弃。已补在底部条 |
| 5 | **led_* 无数据源** | led_dist/led_chor/led_dly 暗灰↔高亮联动 | FPGA **不回显** led 图片切换 ⇒ 初版**省略**（或做静态装饰点）；要联动需 RTL 加发 `.pic` 帧（后续工作） |
| 6 | **字号爆炸** | 11/12/13/14/15/16/18/20/22/24/32/48 共 12 档 | 合并为 **6 档字库**（12/16/20/24/32/48），见 §二 |
| 7 | **特殊符号字库缺口** | ● ➔ ⬅ ★ ► ── · ↕ 直接写在文案里 | 这些符号**不在默认字符集**，⭐ 必须手工加进字库，否则显示方块。见 §七 |
| 8 | **两页重名控件行为未说明** | z_pd/z_vd 在 page0、page1 各有一个 | 合法（控件页私有），但 ⚠️ **FPGA 帧只作用于当前页**，见 §八-1 |
| 9 | **切页陈旧值问题** | 未提及 | b_fx 切到 page1 期间 FPGA 的 page0 更新帧**全部被屏丢弃**，返回 page0 显示旧值。配套方案见 §八-2（**需 RTL 小改**，约半小时，随时可做） |
| 10 | **t_loop 三态配色不可实现** | 空闲灰/录音红/回放绿 | FPGA 只发 `t_loop.txt`、**不发 pco/bco** ⇒ 初版固定配色，状态只改文字（RTL 加发颜色帧 = 后续工作） |
| 11 | 🔴 **触摸命令与 RTL 不符** | `b_dist_hdr` 等发 `printh 65 01 02 01 FF FF FF` | 0x65 触摸帧 body 只有 1 字节（控件 ID），FPGA 只认 ID **0/2**（`uart_ui.v:517-532`）⇒ v2 三个效果器头部按钮**全是空响**。改用翻转变量 `71 19 <bit>`（需 RTL 加 0x19，3 行，§八-2） |
| 12 | **FPGA 已支持但没做按钮** | t_mode/t1 标注"外部硬件按键切换" | RTL 实锤支持屏触摸：ID0=模式翻转、ID2=Test Mode 切档 ⇒ 新增 **`b_mode`**、**`b_test`** 两按钮（§三、§六） |

---

## 一、⭐ 建工程（第一步）

| 项 | 填什么 |
|---|---|
| **设备型号** | 按实物选（TJC X2 系列 1024×600） |
| **方向** | 横屏 1024 × 600 |
| ⭐⭐ **工程编码** | 🔴 **`UTF-8`**（⛔ 不是 GB2312/GBK；⛔ 选错不能事后改） |
| **波特率** | 🔴 **115200**（= FPGA 板载口 BAUD_DIV=434，2026-10-28 改档后） |
| **页面** | `page0`（演奏看板）+ `page1`（效果器链） |

> ⭐ 页面背景色：page0 / page1 属性里设 **63454**（#F0F3F6 浅灰底）。

---

## 二、⭐ 字号合并方案（12 档 → 6 档字库）

| 字库 | 字号 | 字体（字库制作工具里选） | 勾"字体加粗" | 用在哪 |
|---|---|---|---|---|
| 库① | **12** | ⭐ **微软雅黑** | ❌ 不勾 | 各 l_ 标签、t_conn、t_lock、t_lock_info、t_fx_route、t_fx_uart、l_test |
| 库② | **16** | ⭐ **微软雅黑** | ✅ 勾 | t_vol、t_pedal、t_gear、t_hdmi、t_pd、t_vd、底部 t_*_st、t1、b_oct、b_mode、b_test、cur、gr |
| 库③ | **20** | ⭐ **微软雅黑** | ✅ 勾 | t_mode、t_trans、t_slide、t_loop |
| 库④ | **24** | ⭐ **微软雅黑** | ✅ 勾 | t_drum |
| 库⑤ | **32** | ⭐ **思源黑体 Heavy** | —（本身够粗） | t_timbre |
| 库⑥ | **48** | ⭐ **思源黑体 Heavy** | —（本身够粗） | t_bpm 巨字 |

> ⭐ **字体选择理由**（对照设计图的浅色工业风 = 现代 UI 无衬线粗体）：
> - 正文 12~24：**微软雅黑 + 勾加粗**——最接近设计图的 GitHub 风格粗黑体，字重均匀、小字号清晰
> - 巨字 32/48：**思源黑体 Heavy**（下拉列表里有）——字面宽、笔画厚，"BASS"/"120" 的海报感就靠它
> - 备选：没有思源黑体就用 **微软雅黑 + 勾加粗**全套；**⛔ 别选宋体/楷体/隶书/幼圆**（衬线/圆体与工业风不符）
> - ✅ "字体抗锯齿"保持勾选（你截图里已勾）
> ⚠️ 视觉差异 ≤2px，肉眼无感；6 个库的字符集**统一**（见 §七，一份字符集生成 6 次）。

---

## 三、Page 0：演奏与综合控制看板

### 0. 底板（⭐ 最先建，白色卡片底）

| 控件名 | 类型 | 坐标 (x,y,w,h) | 说明 |
|---|---|---|---|
| `bg_a` | 文本（空文字，bco=65535） | (16, 48, 484, 222) | 卡片 A 底板 |
| `bg_b` | 文本（空文字，bco=65535） | (524, 48, 484, 222) | 卡片 B 底板 |
| `bg_c` | 文本（空文字，bco=65535） | (16, 280, 484, 230) | 卡片 C 底板 |
| `bg_d` | 文本（空文字，bco=65535） | (524, 280, 484, 230) | 卡片 D 底板 |

### 1. 顶栏与系统状态（y: 0..40）

| 控件名 | 类型 | 坐标 | 默认内容 | 前景/背景 (RGB565) | 字库 | 说明 |
|---|---|---|---|---|---|---|
| `l_title` | 文本 | (20, 8, 480, 26) | `FPGA DUAL-AXIS SYNTHESIZER CONSOLE` | 9509 / 透明 | ① | 静态 |
| `t_conn` | 文本 | (760, 10, 160, 22) | 🔴 **`UART 115.2K [ONLINE]`** | 2459 / 透明 | ① | 静态（改档后文字） |
| `p_hb` | 🔴 **双态按钮** | (940, 15, 10, 10) | pic=**0**(灰) / pic2=**1**(绿)，val=0 | — | — | ⭐ 心跳点，见 §六事件代码 |

### 2. 卡片 A：演奏核心区

| 控件名 | 类型 | 坐标 | 默认内容 | 前景/背景 | 字库 | 说明 |
|---|---|---|---|---|---|---|
| `l_card_a` | 文本 | (32, 58, 300, 20) | `CORE PERFORMANCE / 演奏核心` | 22477 / 透明 | ① | 静态 |
| `t_timbre` | 文本 | (32, 86, 210, 48) | `BASS` | 9509 / 63455 | ⑤ | FPGA 回显：BASS/GUITAR/PIANO/PAD |
| `t_mode` | 文本 | (254, 86, 232, 48) | `指板模式 [FRET]` | 2459 / 63455 | ③ | FPGA 回显 |
| 🔴 `b_mode` | **按钮（新增）** | (400, 94, 80, 36) | `切换` | 2459 / 65535 | ② | **叠放在 t_mode 右端上层**，触控翻转模式（RTL：触摸 ID 0），事件见 §六 |
| `t_base` | 🔴 **文本**（v2 是按钮） | (32, 144, 454, 48) | `基准音: C4 (最低音 C3)` | 9509 / 63455 | ③ | FPGA 回显，**纯显示不可点** |
| `b_oct` | 🔴 **按钮（新增）** | (374, 150, 108, 36) | `点击切八度 ↕` | 2459 / 65535 | ② | **叠放在 t_base 右端上层**，触控切换八度，事件见 §六 |
| `t_trans` | 文本 | (32, 202, 210, 52) | `0 SEMI (原调)` | 55264 / 63455 | ③ | FPGA 回显，−12~+12 |
| `t_slide` | 文本 | (254, 202, 232, 52) | `开启 (GLIDE ON)` | 6822 / 63455 | ③ | FPGA 回显 |

### 3. 卡片 B：节奏与循环区

| 控件名 | 类型 | 坐标 | 默认内容 | 前景/背景 | 字库 | 说明 |
|---|---|---|---|---|---|---|
| `l_card_b` | 文本 | (540, 58, 360, 20) | `RHYTHM & LOOPER / 节奏循环 (无节拍器)` | 22477 / 透明 | ① | 静态 |
| `t_bpm` | 文本 | (540, 86, 180, 66) | `120` | 9509 / 63455 | ⑥ | FPGA 回显，48px 巨字 |
| `t_drum` | 文本 | (732, 86, 260, 66) | `开 II [PATTERN II]` | 2459 / 63455 | ④ | FPGA 回显，严格罗马数字 |
| `t_loop` | 文本 | (540, 160, 452, 46) | `● 循环录音中 REC` | 65535 / 52517 | ③ | FPGA 回显文字；🔴 三态配色暂不实现（固定红底反白），见 §八-3 |
| `t_kd` | 文本 | (540, 214, 452, 40) | `键盘打鼓: 关闭 [音符演奏]` | 9509 / 63455 | ② | FPGA 回显 |

### 4. 卡片 C：物理外设监视区

| 控件名 | 类型 | 坐标 | 默认内容 | 前景/背景 | 字库 | 说明 |
|---|---|---|---|---|---|---|
| `l_card_c` | 文本 | (32, 290, 320, 20) | `HARDWARE PERIPHERALS / 物理外设监视` | 22477 / 透明 | ① | 静态 |
| `t_vol` | 文本 | (32, 320, 120, 26) | `主音量: 85%` | 9509 / 透明 | ② | FPGA 回显 |
| `j_vol` | 进度条 | (160, 326, 326, 14) | val=85，🔴 **maxval=100** | 前景 6822 / 背景 — | — | FPGA 回显 `j_vol.val=` |
| `t_pedal` | 文本 | (32, 358, 454, 42) | `[PEDAL 延音踏板: 踩下使能]` | 6822 / 63455 | ② | FPGA 回显 |
| `t_gear` | 文本 | (32, 410, 300, 42) | `推子控制: 档 1 [音高颤音]` | 55264 / 63455 | ② | FPGA 回显 |
| `t_lock` | 文本 | (340, 418, 134, 26) | `[推子: 实时生效]` | 38402 / 65523 | ① | 静态（黄底告警样式） |
| `t_lock_info` | 文本 | (32, 460, 454, 36) | `硬件锁状态: 实时响应` | 22477 / 63455 | ① | 静态 |

### 5. 卡片 D：多维调制生态区

| 控件名 | 类型 | 坐标 | 默认内容 | 前景/背景 | 字库 | 说明 |
|---|---|---|---|---|---|---|
| `l_card_d` | 文本 | (540, 290, 360, 20) | `MODULATION & HDMI / 调制与投屏生态` | 22477 / 透明 | ① | 静态 |
| `t_hdmi` | 文本 | (540, 320, 452, 44) | `HDMI: 实时示波器 (波形显示)` | 2459 / 63455 | ② | FPGA 回显（波形/李萨如/频谱三态） |
| `t_pd` | 文本 | (540, 374, 180, 24) | `音高颤音: 25%` | 9509 / 透明 | ② | FPGA 回显 |
| `z_pd` | 仪表 | (580, 402, 100, 100) | val=25，🔴 **maxval=100** | 前景 2459 | — | FPGA 回显 `z_pd.val=` |
| `t_vd` | 文本 | (770, 374, 180, 24) | `音量颤音: 60%` | 9509 / 透明 | ② | FPGA 回显 |
| `z_vd` | 仪表 | (810, 402, 100, 100) | val=60，🔴 **maxval=100** | 前景 55264 | — | FPGA 回显 `z_vd.val=` |

### 6. 底部常驻状态条（y: 520..596）

| 控件名 | 类型 | 坐标 | 默认内容 | 前景/背景 | 字库 | 说明 |
|---|---|---|---|---|---|---|
| `t_dist_st` | 文本 | (64, 547, 110, 26) | `失真 [关]` | 22477 / 透明 | ② | FPGA 回显 |
| `t_chor_st` | 文本 | (224, 547, 110, 26) | `合唱 [开]` | 6822 / 透明 | ② | FPGA 回显 |
| `t_dly_st` | 文本 | (384, 547, 110, 26) | `延迟 [开]` | 55264 / 透明 | ② | FPGA 回显 |
| 🔴 `l_test` | 文本（**新增**） | (510, 547, 44, 26) | `TEST` | 22477 / 透明 | ① | 静态小标 |
| 🔴 `t1` | 文本（**新增**） | (554, 547, 64, 26) | `关` | 22477 / 透明 | ② | 🔴 **FPGA 回显 `t1.txt`（关/4/8/16/32），必须有此控件** |
| 🔴 `b_test` | **按钮（新增）** | (620, 545, 68, 28) | `切档` | 22477 / 65535 | ② | 触控 Test Mode 切档（RTL：触摸 ID 2），事件见 §六 |
| `b_fx` | 按钮 | (704, 526, 292, 64) | `进入五级效果器拓扑链 ➔` | 65535 / 2459 | ② | 触控切页，事件见 §六 |

> ⚠️ v2 的 led_dist/led_chor/led_dly（状态圆点）**本版省略**——FPGA 不回显图片切换（§〇-5）。要加回时用图片控件 + 两张 16×16 圆点图（tools/gen_hb_dots.py 可改尺寸重生成）。

---

## 四、Page 1：五级效果器拓扑链中枢

> 🔴 **初版定位：静态展板 + 三个活值**。除 z_pd / z_vd / t_pd_val 不适用外——page1 上有 FPGA 数据源的只有 **z_pd、z_vd**（与 page0 同名，见 §八-1）；其余 t_*_val / cur / gr / z_dg 等 **FPGA 尚无回显帧**（§八-4）。先按静态值摆，动态化是 RTL 后续工作。

### 1. 顶栏（y: 0..44）

| 控件名 | 类型 | 坐标 | 默认内容 | 前景/背景 | 字库 |
|---|---|---|---|---|---|
| `l_fx_title` | 文本 | (20, 10, 320, 24) | `FX PEDALBOARD TOPOLOGY CHAIN` | 9509 / 透明 | ① |
| `t_fx_route` | 文本 | (360, 10, 480, 24) | `IN ──► SERIAL AUDIO BUS (24-BIT/48K) ──► OUT` | 2459 / 透明 | ① |
| `t_fx_uart` | 文本 | (896, 9, 112, 26) | 🔴 **`UART 115.2K 8N1`** | 6822 / 63455 | ① |

### 2. 五通道单块（x: 24..1000，每块宽 162，y: 62..514）

| 单块 | 头部按钮（触控） | 仪表×2 | 数值文本×2 | 底部说明 |
|---|---|---|---|---|
| 1 音高颤音 PITCH VIB | `b_pv_hdr` (24,62,162,106)：`printh 71 05 01 FF FF FF` | `z_pd`(63,198,84,84) ⭐活值 · `z_pr`(63,328,84,84) | `t_pd_val`(63,284,84,24) `25%` · `t_pr_val`(63,414,84,24) `5.2Hz` | `t_pv_ft`(36,464,138,34) `硬件推子直通` |
| 2 高增益失真 DIST | `b_dist_hdr` (226,62,162,106)：🔴 `printh 71 19 01 FF FF FF`（等 RTL 0x19） | `z_dg`(263,198,88,88) · `z_dt`(265,328,84,84) | `t_dg_val` `+18dB` · `t_dt_val` `-3.5dB` | `t_dist_ft`(238,464,138,34) `★ EC11 正在调节`（底 65523） |
| 3 立体声合唱 CHORUS | `b_chor_hdr` (430,62,162,106)：🔴 `printh 71 19 02 FF FF FF`（等 RTL 0x19） | `z_cl`(469,198,84,84) · `z_mx`(469,328,84,84) | `t_cl_val` `12.5ms` · `t_mx_val` `40%` | `t_chor_ft`(442,464,138,34) `两级共用干湿比` |
| 4 模拟磁带延迟 DELAY | `b_dly_hdr` (634,62,162,106)：🔴 `printh 71 19 04 FF FF FF`（等 RTL 0x19） | `z_ll`(673,198,84,84) · `z_lf`(673,328,84,84) | `t_ll_val` `350ms` · `t_lf_val` `55%` | `t_dly_ft`(646,464,138,34) `独立反馈回路` |
| 5 音量颤音 TREMOLO | `b_vv_hdr` (838,62,162,106)：`printh 71 05 02 FF FF FF` | `z_vd`(877,198,84,84) ⭐活值 · `z_vr`(877,328,84,84) | `t_vd_val`(877,284,84,24) `60%` · `t_vr_val` `3.8Hz` | `t_vv_ft`(850,464,138,34) `硬件推子直通` |

> ⚠️ 所有仪表 maxval=100；z_pr/z_vr（速率 1~20Hz）maxval=20。
> ⚠️ "点击设为 EC11 目标"：仪表控件有触摸事件，代码等协议定稿后补（§八-4）。

### 3. 底部（y: 532..592）

| 控件名 | 类型 | 坐标 | 默认内容 | 前景/背景 | 字库 |
|---|---|---|---|---|---|
| `cur` | 文本 | (24, 542, 340, 40) | `EC11 旋钮锁定: 失真 · 增益 (0x11)` | 37134 / 65523 | ② |
| `gr` | 文本 | (378, 542, 350, 40) | `推子硬件: [档 1 · 音高颤音] · [实时]` | 20781 / 64764 | ② |
| `b_back` | 按钮 | (742, 540, 258, 44) | `⬅ 返回演奏看板 (PAGE0)` | 65535 / 2056 | ② |

---

## 五、颜色速查（RGB565 十进制，⭐ 上位机里填这个）

| 颜色 | Hex | RGB565 |
|---|---|---|
| 页面浅灰底 | #F0F3F6 | 63454 |
| 卡片白 / 浅填充 | #FFFFFF / #F6F8FA | 65535 / 63455 |
| 深炭黑正文 | #24292F | 9509 |
| 次级灰 | #57606A | 22477 |
| 电光蓝 | #0969DA | 2459 |
| 森林绿 | #1A7F37 | 6822 |
| 心跳绿 | #2DA44E | 2016 |
| 琥珀金 | #D97706 | 55264 |
| 警戒红 | #CF222E | 52517 |
| 黄底告警 | #FEF3C7 | 65523 |
| 深蓝黑（b_back 底） | #0F172A | 2056 |

---

## 六、⭐⭐ 事件代码速查（逐个粘进对应事件页）

### 心跳闪烁（page0）

**tm0**（定时器，tim=500，en=1）事件：
```
if(p_hb.val==0)
{
  p_hb.val=1
}else
{
  p_hb.val=0
}
```

**tm1**（定时器，tim=1500，en=1）事件：
```
tm0.en=1
```

> 运行逻辑：FPGA 每秒发 `tm1.tim=1500`（RTL 已交付，148 checks PASS）持续复位 tm1 倒计时 ⇒ 联机时 tm1 永不超时；断联 ≤1.5s 后 tm1 超时 → `tm0.en=1` → 圆点闪。
> ⚠️ p_hb 是双态按钮，**手指点它会手动翻状态**——10×10 在角落，基本点不到。

### 切页按钮

**b_fx** 弹起事件：`page page1`
**b_back** 弹起事件：`page page0`

### 基准音切八度（新增 b_oct）

**b_oct** 弹起事件——⭐ 屏侧自记账版（今天就能用，不依赖 RTL 改动）：
```
// 需先建全局变量 va_base（变量控件，vscope=全局，初值 0）
if(va_base.val==0)
{
  va_base.val=12
  printh 71 01 18 FF FF FF
}else
{
  if(va_base.val==12)
  {
    va_base.val=24
    printh 71 01 30 FF FF FF
  }else
  {
    va_base.val=0
    printh 71 01 00 FF FF FF
  }
}
```
> ⚠️ 局限：若**硬件侧**也改过起始音，屏的 va_base 会记偏。彻底修法 = RTL 加循环变量 0x1B（§八-2），届时 b_oct 只发一句 `printh 71 1B 01 FF FF FF`。

### 模式切换（新增 b_mode）

**b_mode** 弹起事件（RTL 实锤支持：触摸 ID 0 = 模式翻转，`uart_ui.v:517`）：
```
printh 65 00 00 FF FF FF
```

### Test Mode 切档（新增 b_test）

**b_test** 弹起事件（RTL 实锤支持：触摸 ID 2，关→4→8→16→32→关，`uart_ui.v:520`）：
```
printh 65 00 02 FF FF FF
```

### page1 五个头部按钮

```
b_pv_hdr：  printh 71 05 01 FF FF FF      // 切档 1（音高颤音）
b_vv_hdr：  printh 71 05 02 FF FF FF      // 切档 2（音量颤音）
```

🔴 **效果器开关三兄弟——v2 的 `printh 65 01 02 01 …` 是错的（空响），改成翻转变量**（等 RTL 加 0x19 后启用）：
```
b_dist_hdr：printh 71 19 01 FF FF FF      // 翻转失真 Bit0
b_chor_hdr：printh 71 19 02 FF FF FF      // 翻转合唱 Bit1
b_dly_hdr： printh 71 19 04 FF FF FF      // 翻转延迟 Bit2
```
> ⚠️ RTL 加好 0x19 之前，这三个按钮**先别绑命令**（绑了也白绑，还可能发垃圾字节干扰解析）。

### ⭐ 返回 page0 主动刷新（🔴 需 RTL 配套，暂缓）

**page0 后初始化事件**（等 §八-2 的 RTL 改完再加）：
```
printh 88 FF FF FF
```

---

## 七、⭐⭐ 字库字符集（⭐ 生成 6 份，每份粘同一行）

### 7.1 中文（一次全选复制）

```
演奏核心节奏循环无拍器物理外设监视调制与投生态指板模式变调音高颤量开关启闭基准最低原录音回放武装中空闲键盘打键位演奏主延踏板踩使能松推子控制档实示波波形显示李萨如图谱失真合硬件直通级共干湿比反馈路独立进五效果拓扑链点击切八度旋钮锁定增益补偿延迟时间长度模拟磁立体声返回看板深度速率正在调节锁状态响
```

### 7.2 🔴 特殊符号（⛔ 不加必显示方块）

```
● ➔ ⬅ ★ ► ─ · ↕
```

### 7.3 ASCII

字库工具勾选完整 ASCII（数字/字母/括号/百分号/冒号/方括号等全用到了）。

> ⭐ 生成步骤：工具 → 字库制作 → 编码 🔴 **UTF-8** → 字号选一档 → 粘贴 §7.1+§7.2 字符 → 生成。6 档字号各生成一次。
> ⚠️ 下载工程时**字库必须随工程一起下屏**，否则中文/符号全部方块。

---

## 八、⚠️ 已知边界与后续工作（⭐ 逐条有主）

### 1. z_pd / z_vd 两页重名（合法但要懂行为）

控件是页私有的，两页各有一个 `z_pd` **不冲突**；但 FPGA 发 `z_pd.val=25` 只作用于**当前显示页**的那个。page1 的 z_pd（深度旋钮）与 page0 的 z_pd（监视弧）本来就是同一个物理量，联机时在哪页哪页活。

### 2. 🔴 RTL 待加三件套（⭐✅ **2026-10-29 已全部落地，tb 148→182 checks PASS**）

> ⭐ 终版清单见 `串口屏v3-搭建清单-20261029.md`（本节留档）。

| # | 改什么 | 屏侧解锁的能力 | 工作量 |
|---|---|---|---|
| A | **0x88 每次收到都全量重发**（现仅首次） | page0 初始化事件 `printh 88 FF FF FF` ⇒ 切页返回永远新值 | ~10 行 + tb 1 判据 |
| B | **翻转变量 0x19**：`fx_mask_o ^= val_q` | page1 三个效果器开关按钮（`71 19 01/02/04`）盲翻转，无状态记账 | ~3 行 + tb 1 判据 |
| C | **八度循环变量 0x1B**：`base_semi 0→12→24→0` | b_oct 单命令循环，不用 va_base 记账 | ~3 行 + tb 1 判据 |

三个都动 `uart_ui.v`，合并一次回归（tb 预计 148→152 checks）。

### 3. t_loop 三态配色

FPGA 只发 `t_loop.txt` 文字。空闲灰/录音红/回放绿需要 FPGA 加发 `t_loop.bco=` / `t_loop.pco=` 帧——RTL 回显 FSM 目前只有 txt/val/tim 三种帧型，加色帧是后续工作。初版固定红底反白。

### 4. Page1 动态数据

z_dg/z_dt/z_cl/z_mx/z_ll/z_lf + t_*_val + cur + gr 目前**无 FPGA 回显帧**。要全动态需在 uart_ui.v 扩字段（每字段约 20 行 RTL + tb 判据）。建议演示前排期评估。

### 5. led_* 状态灯

同 §〇-5，无数据源，本版省略。

---

## 九、✅ 验收清单

### 模拟器（不接 FPGA）

| # | 操作 | 期望 |
|---|---|---|
| 1 | 编译 | ⭐ 0 错误（变量名无效 = 控件没建/名拼错） |
| 2 | 进 page0 | 心跳圆点 500ms 灰绿闪 |
| 3 | 点 b_fx / b_back | 两页互切 |
| 4 | 中文/符号 | 无方块（方块 = 字库没下/字符没进集） |
| 5 | 模拟器串口窗口 | 点 b_oct/b_*_hdr 能看到 printh 的 HEX 输出 |

### 串口助手联调（USB-TTL 接屏，115200）

| # | 发什么（HEX） | 期望 |
|---|---|---|
| 1 | `00 FF FF FF` | 清缓冲（上电防杂波，官方 QA25） |
| 2 | `88 FF FF FF` | 🔴 **收到 22+1 帧全量回显**（t_mode.txt=… 一路到 z_vd.val=…，共约 671 字节）——这是最硬的一条 |
| 3 | 等 1s | 又来一帧 `tm1.tim=1500`（心跳） |
| 4 | 等着不动 | 心跳每秒一帧，圆点常闪不灭（因为 tm1 一直被复位、屏在 page0） |

> ⚠️ 判据 2 若只收到部分帧：检查控件名是否与本清单逐字一致（t_base 不能叫 tBase）。
> ⚠️ 帧尾 `FF FF FF` 是屏的指令结束符，FPGA 自动处理，串口助手手动发时要切 HEX 模式补发。

---

## 附 · 关联

| 想看什么 | 去哪 |
|---|---|
| ⭐ FPGA 回显实现（22 字段+心跳） | `rtl/w3c/uart_ui.v` · tb：`tb/w3c/tb_uart_ui.sv`（148 checks） |
| ⭐ 心跳圆点 PNG 生成脚本 | `tools/gen_hb_dots.py` → `tools/hb_dots/` |
| ⭐ 改档记录（500k→115200） | `rtl/top.v` :1243-1250（五处一致注释块） |
| 旧 2 寸屏（ESP32 侧）文档 | `esp32/串口屏控件清单.md` 等（⛔ 与本屏无关，别混用） |
