hokuu1102/Gowin2026-PolySynth/esp32/上机指南.md

# 🚀 ESP32 上机指南（拿到板子后照这个做）

> **读者**：⭐ **拿到 ESP32 板子后，第一次上机**
> **目标**：⭐ **从"裸板"到"能证明 ESP32 侧喂得对"**（⚠️ 不需要 FPGA）
> **建立**：2026-09-23
> **关联**：`esp32/README.md` · `esp32/ble/README.md` · `esp32/串口屏指令表.md`
> 　　· `files/20-代码/ESP32侧接续准备-20260923.md`

---

## 〇、⭐⭐ 先明确"这次上机能证明什么、⛔ 不能证明什么"

🔴 **这条最重要** —— ⚠️ 否则会误判成 ESP32 的问题：

| 能证明 | ⛔ 不能证明 |
|---|---|
| ✅ 芯片型号对、能烧录、能启动 | 🔴 **FPGA 会出声** |
| ✅ BLE 能连、MTU 协商成功 | 🔴 **按节奏演奏** |
| ✅ ⭐ **ESP32 侧"按谱子时间喂"是对的** | ⚠️ 端到端联调 |
| ✅ 串口屏显示与变色 | — |

⭐ **原因**（⚠️ 已核实）：**FPGA 侧这一环还没接** ——

```
ESP32 ──UART──> uart_rx ──> evt_uart_rx ──> [事件缓冲] ──> play_seq ──> evt_merge 源A
  ✅就绪         ❌没接      ✅模块已有     🔴【不存在】   ✅模块已有    ⚠️源A还接着 demo
```

> ⭐ 证据：`rtl/top.v` 里 **`play_seq` 只出现在一行注释里**，⛔ **没有例化**。
> ⇒ ⭐ **现在烧上去：ESP32 会认真放水，但 FPGA 收不到 ⇒ 不会响。**

⇒ ⭐ **本次上机的判据全部围绕【ESP32 侧自己】**（见 §六）。

---

## 一、⭐ 准备清单（⭐ 先点一遍，⛔ 别开工才发现缺东西）

| # | 需要什么 | ⚠️ 注意 |
|---|---|---|
| **1** | ⭐ **ESP32-S3 开发板** | ⭐ **必须带 PSRAM**（⚠️ 模组型号带 `R`，如 `N16R8`） |
| **2** | USB 线（⭐ 数据线，⛔ 不是只充电的） | ⚠️ S3 有的板子用**原生 USB**（`GPIO19/20`） |
| **3** | ⭐ **USB-TTL 模块**（⭐ 当"假 FPGA"） | ⚠️ 见 §五 的供电提醒 |
| **4** | 串口屏 + **5V 电源** | 🔴 **VCC 必须 5V**（⛔ 3.3V 不亮） |
| **5** | 杜邦线若干 | ⚠️ 建议**短于 30 cm** |
| **6** | PC 已装 ESP-IDF v5.5 | ⭐ `C:\Espressif`（⚠️ EIM 安装） |
| **7** | `pyserial`（⭐ 给 `send_frames.py` 用） | `pip install pyserial` |

---

## 二、⭐⭐ 第一步：确认芯片（⭐ 这步不过，后面全白做）

⭐ **先查出你的板子插在哪个口**（⚠️ **每次插拔都可能变**，⛔ 不要凭记忆）：

```powershell
Get-PnpDevice -Class Ports -PresentOnly |
  Where-Object InstanceId -like '*VID_303A*' |
  Select-Object -ExpandProperty FriendlyName
```

⭐ **期望输出**（括号里就是你的端口号）：

```
USB 串行设备 (COM29)
```

⚠️ **把下面的 `COM29` 换成你上面看到的口**（⭐ 全文其余 `COM29` 同理）。

```powershell
cd C:\Users\hokuu\Desktop\FPGA\FPGA2026-esp32\esp32\ble
.\build.ps1 -Action chipid -Port COM29
```

⭐ **期望输出**：

```
Chip is ESP32-S3 (revision v0.x)
```

> 🔴 **为什么是 `VID_303A`**：Espressif 的专有 USB VID。
> ⚠️ **⛔ 不要用 `COM7` 之类的固定号** —— 本机 `COM7`/`COM8` 是**蓝牙串行口**，
> 照抄会把固件往蓝牙口上烧。

🔴 **判据表**：

| 看到什么 | ⭐ 结论 |
|---|---|
| ⭐ **`Chip is ESP32-S3`** | ✅ **对了，继续** |
| 🔴 **`ESP32-D0WD`** | 🔴 **这是经典版** ⇒ ⛔ **烧 `esp32/bridge/`（SPP 版），⛔ 不是这个** |
| 🔴 **`ESP32-S2`** | 🔴 **S2 没有 BLE 主机栈可用性差** ⇒ ⚠️ 停下来问 |

### 2.1 ⚠️ 顺手确认 **PSRAM**（⭐ 模式 B 靠它放整曲）

⭐ **最省事的办法**：上面 `chipid` 的输出里**直接就有** —— 看这一行：

```
Features: WiFi, BLE, Embedded PSRAM 8MB (AP_3v3)
```

| 看到 | ⭐ 结论 |
|---|---|
| ✅ **`Embedded PSRAM 8MB`** | ✅ **有 PSRAM，继续** |
| 🔴 **没有 `PSRAM` 字样** | ⚠️ **模组没 PSRAM** ⇒ 见下方后果 |

> ⚠️ **⛔ 不要用 `python -m esptool ... flash_id`** —— 系统 python 里**没有 `esptool`**
> （它只存在于 ESP-IDF 环境内部），敲了会报 `No module named esptool`。
> ⭐ **烧完看启动日志的 `SPIRAM` 字样**（见 §四）是另一个有效办法。

🔴 **没有 PSRAM 的后果**：
⚠️ 水池会**优雅降级**到内部 DRAM（⭐ **能跑，但放不下整曲 104.3 KB**）⇒
⭐ **断链容忍从"整曲"降到约 60 秒** —— ⚠️ **不是不能用，是余量小**。

---

## 三、⭐ 第二步：编译并烧录

```powershell
cd C:\Users\hokuu\Desktop\FPGA\FPGA2026-esp32\esp32\ble

# ⭐ 编译（⭐ 默认就是模式 B）
.\build.ps1 -Action build

# ⭐ 烧录（⚠️ COM29 换成你 §二 查到的口）
.\build.ps1 -Action flash -Port COM29

# ⭐ 看日志（⭐ 出了事第一个看这个）
.\build.ps1 -Action monitor -Port COM29
```

> ⚠️ **`monitor` 退出用 `Ctrl + ]`**（⛔ 不是 Ctrl+C）。

### 3.1 ⚠️ 要切模式 A 时（⭐ 有坑）

```powershell
.\build.ps1 -Action build -Mode 0     # 模式 A（透传）
.\build.ps1 -Action build -Mode 1     # 模式 B（水池，默认）
```

⚠️ **`build.ps1` 会在切换时自动删 `build/`** ——
🔴 **因为 CMake 缓存会粘住上一次的 `-D` 值**（⭐ 见经验 `C61` / `T95`）。

⭐ **怎么确认模式真的生效**：⚠️ **看体积** ——

| 模式 | ⭐ 参考体积 |
|---|---|
| ⭐ **B（默认）** | `0xc1250` |
| A | ⚠️ 略小 |

⚠️ **两次体积完全相同 ⇒ 开关没生效**（⭐ 这是这条经验的判据）。

---

## 四、⭐⭐ 第三步：看启动日志（⭐ 一眼确认三件事）

⭐ 上电后 `monitor` 里应该看到：

```
=== ESP32-S3 BLE <-> UART bridge ===
mode = B / POOL (buffer whole score, self-paced)
uart=1 baud=500000 tx=GPIO17 rx=GPIO18 frame=9B name=FPGA2026-Synth
```

⭐ **要点检的三条**：

| # | 看什么 | ⭐ 期望 | 🔴 不对说明 |
|---|---|---|---|
| **1** | `mode = B / POOL` | ⭐ **模式 B** | ⚠️ 编译时模式没切对 |
| **2** | `baud=500000` | ⭐ **500 kbps**<br>🔴🔴 **2026-09-30 更正**：⚠️ 原写「`baud=1000000` / 1 Mbps」⇒ 🔴 **已作废**。⭐ 现值 = **`500000`**（`esp32/ble/main/ble_config.h` `BLE_BAUD 500000`）；⭐ FPGA 侧 2026-09-24 已降档 | 🔴 **若日志仍显示 `1000000` ⇒ 固件没烧对**（⭐ 见 §6.3） |
| **3** | ⭐ **有没有 `SPIRAM` 相关行** | ⭐ **有** | 🔴 无 ⇒ 模组**没有 PSRAM** |

⚠️ **还要看有没有报错**：
- 🔴 `pool reset: NO MEMORY` ⇒ ⚠️ 水池分配失败（⭐ PSRAM 与 DRAM 都不够）
- 🔴 `create attr tab FAILED` ⇒ 🔴 **GATT 属性表建失败**（⭐ 后面 BLE 一定连不上）

---

## 五、⭐ 第四步：接线（⭐ 两块**分开**接，⛔ 别混）

### 5.1 ⭐ 串口屏（⭐ 独立 UART，与 FPGA 那条互不影响）

| 屏引脚 | → | ESP32-S3（BLE 版） |
|---|---|---|
| **VCC** | ← | 🔴 **5 V**（⛔ **不是 3.3 V**） |
| **GND** | — | GND |
| **TX** | → | **`GPIO5`**（RX） |
| **RX** | ← | **`GPIO4`**（TX） |

⭐ **波特率 `115200`**（⭐ 必须与屏 `program.s` 里的 `bauds` 一致）。

### 5.2 ⭐ USB-TTL 当"假 FPGA"

| USB-TTL | → | ESP32-S3 |
|---|---|---|
| **TX** | → | **`GPIO18`**（RX） |
| **RX** | ← | **`GPIO17`**（TX） |
| **GND** | — | 🔴 **必须共地** |
| **5V** | ⛔ **不要接** | ⚠️ ESP32 自己从 USB 取电 |

⚠️ **波特率 `500000`** —— 🔴🔴 **2026-09-30 更正**：⚠️ 原文写 `1000000`（1 Mbps）⇒ 🔴 **已作废**。
⭐ 两侧现值都是 **500 k**（⭐ ESP32 侧 `ble_config.h` `BLE_BAUD 500000`；⭐ FPGA 侧 2026-09-24 降档）。
⚠️ **不同档 ⇒ 静默乱码**（⭐ 不报错）⇒ 🔴 **先核对两侧**：
- ⭐ **先量 USB-TTL 实际跑的档位**（⭐ 现在只要 **500 k**，比 1 Mbps宽松得多）
- ⚠️ 或**临时把固件改成 `115200`**（`ble_config.h` 的 `BLE_BAUD`，⭐ 可用 `-DBLE_BAUD=` 覆盖）先跑通

---

## 六、⭐⭐ 第五步：灌数据 + 验收（⭐ 本次上机的**正题**）

### 6.1 先做**离线自检**（⭐ 确认 PC 侧工具是好的）

```powershell
cd C:\Users\hokuu\Desktop\FPGA\FPGA2026-esp32\esp32\tools
python send_frames.py --selftest
```

⭐ **期望**：**8/8 全过**（⚠️ 这一步 ⛔ 不需要任何硬件）。

### 6.2 灌数据

```powershell
# ⭐ 先小量试（200 事件）
python send_frames.py --port COM8 --events 200

# ⭐ 模式 B 就该"一口气灌完"
python send_frames.py --port COM8 --events 200 --full-speed
```

⚠️ **`COM8` 换成 USB-TTL 的串口号**（⛔ **不是 ESP32 自己的下载口**）。

### 6.3 ⭐⭐ 验收判据（⭐ 逐条对，⛔ 别只看"跑完了"）

⭐ **ESP32 日志每 1 秒打一行**，重点看这几个字段：

| 字段 | ⭐ 期望 | 🔴 不对说明 |
|---|---|---|
| ⭐ **`total=`** | ⭐ **= 你发的事件数**（如 200） | 🔴 0 ⇒ **总数帧没收到** |
| ⭐ **`tf=`** | ⭐ **1** | 🔴 0 ⇒ 同上；⚠️ >1 ⇒ PC 发了多次 |
| ⭐ **`rst=`** | ⭐ **4** | ⚠️ 复位序列帧数（⭐ 4 帧 = 36 字节） |
| 🔴 **`unk=`** | ⭐ **恒为 0** | 🔴 **非 0 ⇒ 对端发了 ESP32 不认识的东西** |
| ⭐ **`pool=N/…`** | ⭐ **N = 你发的事件数** | 🔴 少 ⇒ 丢帧 |
| 🔴 **`ovf=`** | ⭐ **恒为 0** | 🔴 **非 0 ⇒ 池满丢帧** |
| 🔴 **`mismatch=`** | ⭐ **恒为 0** | 🔴 **非 0 ⇒ 实收 ≠ 应到**（⭐ 发送被截断） |
| ⚠️ **`clamp=`** | ⚠️ **可以有值** | ⭐ 含义：tick 限流截断次数（⚠️ 大 = 老落后，⭐ 但**不致命**） |
| ⭐ **`sent=`** | ⭐ **会自己往上涨**（⭐ 模式 B 按谱子时间放） | 🔴 一直 0 ⇒ 没起播 |

⭐⭐ **最关键的三条**：**`unk=0`** · **`ovf=0`** · **`mismatch=0`**
（⭐ 这三个**非 0 都是真故障**，⛔ 不是"正常的波动"）。

### 6.4 ⭐ 串口屏应该显示什么

| 屏上控件 | ⭐ 期望 |
|---|---|
| `t0` + `g0` | `曲谱：` + 曲谱名 |
| `j0` + `n0` | ⭐ **进度条会动、百分比非 0**（⭐ 这是本次修好的） |
| `t1` | 状态字（`待机` / `灌谱中` / `就绪` …） |
| `t2` | ⭐ **`4820/11865` 形式**（⛔ **不再是 `4820/0`**） |
| `t3` | `BT --`（红）/ `BT OK`（绿） |

⚠️ **`t2` 若还是 `x/0`** ⇒ 🔴 **总数帧没被解析**（⭐ 查 `tf=`）。

---

## 七、⭐⭐ 第六步：BLE 真机连通

⭐ 这块**不依赖 USB-TTL**（也不依赖任何接线）。

### 7.1 ⭐ 用手机（推荐：nRF Connect）

| # | 做什么 | ⭐ 期望 |
|---|---|---|
| **1** | 装 **nRF Connect**（Nordic 官方） | — |
| **2** | 扫描 | ⭐ 看到 **`FPGA2026-Synth`**（⚠️ MAC 应为 `94:A9:90:2D:A6:6x`） |
| **3** | ⭐ **点 `CONNECT`** | ⭐ 日志打 `BLE CONNECTED` |
| **4** | ⭐ **看 `FLAGS & SERVICES` → `SERVER`** | ⭐ 出现服务 **`0xABF0`** |
| **5** | ⭐ **找到 `0xABF2`，点它的"三个向下箭头"** | ⭐ **订阅**（= 写 CCCD）<br>⚠️ **不点这个就收不到 ESP32 发的** |
| **6** | ⭐ **找到 `0xABF1`，点上传箭头 → `BYTE ARRAY`** | ⭐ 写入数据 |
| **7** | ⭐ **看日志 `ble_rx=`** | ⭐ **应等于你写入的字节数** |

⭐ **第一次验证建议写 9 个字节**：`A5 A5 A5 A5 A5 A5 A5 A5 A5`
（⭐ 全 `A5` = 复位标记帧）

⭐ **期望日志**：

```
I blebridge: ble_rx=9 | ... | rst=1 | unk=0 | ... | CONN
```

| 字段 | ⭐ 判读 |
|---|---|
| **`ble_rx=9`** | ✅ **收到 9 字节**（通路已通） |
| **`rst=1`** | ✅ **识别为 1 个复位标记帧**（⭐ 正确行为） |
| **`unk=0`** | ✅ **无未知帧头** |
| **`pool=` 不变** | ✅ **正确**（复位帧本该被丢弃，不进水池） |

### 7.2 ⚠️ 四条容易卡住的

| # | 坑 | ⭐ 说明 |
|---|---|---|
| **1** | 🔴 **必须订阅 `0xABF2`** | ⭐ 它的 CCCD 要写 `0x0001` —— ⚠️ **App 里就是"三个箭头/使能通知"那个开关** |
| **2** | ⚠️ **`0xABF1` 显示"不支持通知"是正常的** | ⭐ 它是**写入口**（⛔ 不是通知口）—— ⚠️ **别以为坏了** |
| **3** | ⚠️ **MTU 影响吞吐** | ⚠️ 默认 23 ⇒ 有效载荷仅 20 字节<br>⭐ **nRF Connect / PC 桥会请求大 MTU ⇒ 协商到 `mtu=517`** |
| **4** | ✅ **`0xABF3`（CMD）已可写**<br>🔴🔴 **2026-10-01 更正**：⚠️ 2026-09-30 那版写「⭐ **`0x01` = 清池** · ⭐ **`0x02` = 状态上报**（⭐ 回读 `0xABF4`）；⚠️ **故意不做 start/stop**（⭐ 起播架构尚未裁定）」⇒ 🔴 **已作废**。⭐ **现为四个命令**（`esp32/ble/main/ble_main.c` 的 `case 0x01` / `0x02` / `0x03` / `0x04`；⭐ 截至提交 `35036bf` 在 `:606` / `:611` / `:629` / `:634`，⚠️ **行号会漂，⛔ 别写死**）：<br>· ⭐ **`0x01` = 清池** · ⭐ **`0x02` = 状态上报**（⭐ 回读 `0xABF4`）· ⭐ **`0x03` = 起播（START）** · ⭐ **`0x04` = 停止（STOP）**<br>⭐ 依据：⭐ 用户 2026-09-30 已裁定**走模式 B、起播键在 ESP32**（`files/20-代码/用户裁定结果-20260930.md` §〇）⇒ ⭐ 不再"架构未定" | ⭐ **`0xABF4`(STAT) 也已可读**（🔴 原用 `ESP_GATT_AUTO_RSP` + `length=0` ⇒ **读回空**；⭐ 已改 `ESP_GATT_RSP_BY_APP`，⭐ 证据 `gatt_svc.c:180`~`:182`）<br>🔴🔴 **2026-10-01 更正**：⚠️ 原写「⭐ 实测返回 `pool=0/18204 sent=0 ovf=0\|ring=0 u_drop=0/0`」⇒ 🔴 **那是旧的三组短格式，已作废**。⭐ 现值 = **六组**（`V1 mode=` · `pool=` · `ring=` · `ble=` · `uart=` · `frame=` · `cmd=`；`ble_main.c:336` `cmd_report_status()`，缓冲区 **256 B** 见 `gatt_svc.c:99`）<br>⭐ **`V1` 行带 `req=`（快照序号）/ `up=`（生成时刻）** ⇒ ⭐ **陈旧变得【可判定】**（提交 `35036bf`；⚠️ 连读两次 `req` 不变 ⇒ 🔴 数据是旧的）<br>🔴 **但它仍是【拉取快照】**：⭐ **只有先发 `CMD 0x02` 才刷新**（`cmd_report_status()` **只**被 `case 0x02` 调用，⭐ 截至 `35036bf` 在 `:613`）⇒ ⚠️ **不发就直读 = 上一次的内容**（⭐ 能判定，⚠️ 但**不自动刷新**）（⭐ 配套工具 `esp32/tools/stat_read.py`）<br>🔴 **尺寸警告**：⭐ 代表性样本 **261 B** > `char buf[256]`（`ble_main.c:352`）⇒ ⚠️ **可能截断尾部（`cmd=` 组）** |

### 7.3 ✅ 用 PC 端 BLE 桥（🔴 **2026-09-30 更正**）

> 🔴🔴 **2026-09-30 更正**：⚠️ 本节原标「⚠️ 自动化灌数据【尚未打通】」⇒ 🔴 **已作废**。
> ⭐ **已改用 `bleak` 直连**（⭐ **绕开虚拟串口**）⇒ ⭐ **自动化灌数据已打通**：
> · ⭐ `esp32/tools/send_frames_ble.py` —— PC 侧 BLE 直连灌数据
> · ⭐ `esp32/tools/e2e_accept.py` —— **一键端到端**（清池 → 灌 → 起播 → 抓包 → 判据表）
> ⚠️ 下表是**旧的桥工具路径**（⭐ 保留供追溯，⛔ 不再推荐）。

⭐ 工具：`C:\Users\hokuu\software\BLE-Serial-Tool\BLE_serial.exe`

| # | 操作 | ⭐ 填什么 |
|---|---|---|
| **1** | 扫描设备 | ⭐ **`FPGA2026-Synth`** |
| **2** | 点**快速连接** | 程序自动枚举 GATT |
| **3** | ⭐ **选【发送】特征** | ⭐ **`0xABF1`** |
| **4** | ⭐ **选【接收】特征** | ⭐ **`0xABF2`** |

| 路径 | ⭐ 实测结果（2026-09-24） |
|---|---|
| 桥工具**界面发送框** → ESP32 | ✅ **通**（`ble_rx=9`） |
| 脚本 → `COM11` → 桥 → ESP32 | 🔴 **不通**（`ble_rx=0`） |

⚠️ **注意**：桥工具是**懒连接** —— ⭐ **打开 `COM11` 时才建立 BLE 连接**。
🔴 **`COM11` 不在 `pyserial` 端口枚举里**（但能 `open()`）⇒ ⚠️ **虚拟串口对可能没真正建好。**
⭐ **待办**：改用 Python + `bleak` 直接走 BLE（⛔ 绕开虚拟串口）。

---

## 八、⚠️ 出问题先查这六条（⭐ 按概率排序）

| # | 现象 | ⭐ 先查 |
|---|---|---|
| **1** | 🔴 **ESP32 完全没反应** | ⭐ **两侧波特率同档**（⭐ 现应都是 **500 k**）+ **USB-TTL 实际档位** + **共地**（⭐ 见经验 `手册 27`） |
| **2** | 🔴 **`unk=` 一直在涨** | 🔴 **对端发的东西 ESP32 不认识** ⇒ 查是不是把 `FF FF FF` 当字符发了 |
| **3** | 🔴 **`pool=0`**（一帧都没进池） | ⚠️ 帧头不对 ⇒ 查 PC 侧到底发了什么字节 |
| **4** | ⚠️ **屏上没变化** | ⭐ 先看**屏的回显**（⭐ 有回显=指令到了）；⚠️ 再查 `font` 指向的字库存不存在 |
| **5** | 🔴 **BLE 连不上** | ⚠️ 查日志有没有 `create attr tab FAILED`（⭐ 属性表没建起来） |
| **6** | ⚠️ **`SPIRAM` 没有** | 🔴 **模组真没 PSRAM** ⇒ ⚠️ 水池降级（⭐ 能跑但余量小） |

---

## 九、⭐ 上机记录表（⭐ 建议边做边填，⛔ 别凭记忆）

| # | 项 | ⭐ 实测值 | ✅/🔴 |
|---|---|---|---|
| 1 | 芯片型号 | | |
| 2 | 有无 PSRAM | | |
| 3 | `mode` | | |
| 4 | binary 体积 | | |
| 5 | `send_frames.py --selftest` | | |
| 6 | `total=` | | |
| 7 | `tf=` / `rst=` | | |
| 8 | 🔴 `unk=` | | |
| 9 | 🔴 `ovf=` | | |
| 10 | 🔴 `mismatch=` | | |
| 11 | MTU 协商值 | | |
| 12 | 屏显示是否正常 | | |

---

## 十、⚠️ 本指南的边界

| # | 说明 |
|---|---|
| **1** | ⚠️ **未在真板上验证过** —— 依据是**固件源码 + 配置 + 官方文档** |
| **2** | 🔴 **本次上机⛔ 不能证明"FPGA 会出声"**（⭐ 见 §〇） |
| **3** | ⚠️ **引脚/波特率可能随模组不同而需调整** ⇒ ⭐ 以 `ble_config.h` 为准 |
| **4** | ⚠️ **`send_frames.py` 发的是【假曲谱】**（⭐ 真曲谱要等 PC 侧发送端接上） |

---

## 附 · 关联

| 想看什么 | 去哪 |
|---|---|
| ⭐ 工程总览（两版区别） | `esp32/README.md` |
| ⭐ BLE 版细节 | `esp32/ble/README.md` |
| ⭐ 串口屏指令（可粘贴） | `esp32/串口屏指令表.md` |
| ⭐ 对接点与联调清单 | `files/20-代码/ESP32侧接续准备-20260923.md` |
| ⭐ PC 侧发送工具 | `esp32/tools/send_frames.py` |
| ⭐ 9N 对齐为什么是关键 | `files/20-代码/ESP32通路总体架构-20260922.md` §三 |
