hokuu1102/Gowin2026-PolySynth/review/下个会话prompt-20261014.md

# 下个会话 Prompt（2026-10-14）—— 直接复制粘贴

> 用法：新开一个会话，把下面 `---` 之间的**全部内容**作为第一条消息发出去。

---

接手 `C:\Users\hokuu\Desktop\FPGA\FPGA2026`（Tang Console 60K / Gowin GW5AT-LV60PG484AC1）。

**先读** `review/交接文档-20261014.md`（刚写的，含完整状态、根因、命令、坑），再动手。

## 背景一句话

上一轮修好了用户上板报的两个 bug（`'A'` 模式切换命令失效 + 颤音推子无感），
回归曾 157/157、PnR 0 setup/0 hold、位流已产出，**但还没烧进板子**（当时板子从 USB 掉线了）。

## 你的任务：收口这个周期

### T1（先做）重跑全量回归

```
powershell -NoProfile -ExecutionPolicy Bypass -File sim\tb_all.ps1
```

原因：最后两处改动（`rtl/w3b/vibrato_lfo.v` 的编译期守卫、`tb/w3c/tb_uart_ui.sv` 的 5 条判据）
**在最后一次回归之后**，账还没做实。

**通过判据**：运行结束打印的「通过 N / 共 N」**两数相等**（别写死 157）。
约 15 分钟 ⇒ **挂后台作业**，别前台干等。

### T2 烧新位流

```powershell
# 先确认板子在
Get-PnpDevice -PresentOnly | Where-Object { $_.InstanceId -match 'VID_0403' }
# 空 = 板子掉线，让用户查 USB 线 / 5V2A 供电 / 换数据线；有输出才继续

cd 'C:\Gowin\Gowin_V1.9.12.03_x64\Programmer\bin'
.\programmer_cli.exe --device GW5AT-60B --operation_index 2 `
  --fsFile 'C:\Users\hokuu\Desktop\FPGA\FPGA2026\impl\pnr\Gowin2026.fs' `
  --cable 'USB Debugger A'
```

- 线缆名必须是 **`USB Debugger A`**（不是 `Gowin USB Cable`）
- `exit code 0` = 成功；`50` + `Cost 0.01 second(s)` = 没真正开始（设备不在/被占）
- **别并发跑两个**，也别同时开着 Gowin Programmer GUI

### T3 让用户上板验 `'A'`

接线：命令串口在 **J9（TX↔D14、RX↔D15）**，经外部 USB-TTL（CH340，当前 COM31）。
参数：**500000 bps 8N1**，**单字母命令，无帧头**。

```
发 'A' → 应回 'a'，且模式在 指板 ⇄ 钢琴 之间翻转
指板模式下不接 LM393 应完全不出声（这才是真切过去了）
```

用户若反馈仍不生效 ⇒ 先查是不是**发到了 ESP32 的口（G22）**，`calib_cmd` 只听板载口 D14。

### T4 用户听完后决定 P2b 怎么修

颤音还剩一层没修（**绝对偏移**导致低音过猛、高音太弱：E1 = 471 cents、A4 = 50、E6 = 17）。
三个方案在交接文档 T4 / `review/上板问题清单-20261013.md` 的 P2b 节。**等用户上板听感再定。**

### T5 用户同意后才 push

**用户原话：「先不要 push，上机之后再 push」。**
推之前：`git tag -f pre-squash/<日期>` + `git bundle` 备份 → `git reset --soft origin/main`
→ 压成 **1 个提交** → `git push origin HEAD:main`。
注意本机 git 走代理 `127.0.0.1:7890` 且**直连 GitHub 不通**，代理没开就推不上去。

## 硬约束（都是踩过的，别重犯）

1. **加一条串口命令要改 6 处，第 6 处是头号陷阱**：
   把 `byte_is_xxx` 加进 `calib_cmd.v` 的 **`byte_is_cmd` 总闸** ——
   上一轮的 `'A'` 就是漏了这步（连命令都不算，不回包、计数器不增、模式不变）。
   空闲字母只剩 **`O` / `U` / `Z`**。
2. **新建 HDL 必须登记进 `Gowin2026.gprj`**（`type="file.verilog"`，`.sv` 也是），
   否则综合**静默丢弃**：不报错、时序正常、位流里没有它。`.gprj` 里注释**只能 ASCII**。
3. **`.ps1` 必须 UTF-8 BOM 或纯 ASCII**（`edit` 会掉 BOM，改完补回）；**HDL 不许有 BOM**。
   改完跑 `tools\check_ps1_encoding.ps1` + `tools\check_no_bom.ps1`。
4. **只用 `edit` 工具改文件**，⛔ 不许"读文本+写文本"整体重写（会把 LF 变 CRLF，整个文件都算改动）。
   改**长行**时 `old_string` 必须覆盖**整行**，否则旧行剩余会变成孤立残行。
5. **PnR 绝不能并发**（两个实例互相破坏输出目录，两边都失败）。
   **PnR 跑时不许改 `rtl/` 或 `constr/`；回归跑时不许改 `rtl/` 或 `tb/`。**
6. **省 LUT 的改动必须实测**模块 Lut 与顶层 CLS 增量，
   ⛔ **不能靠 (N−1) 模型推算当结论**（P0 实测是净亏 +373 Logic，因为综合器早做过了）。
7. **所有说明必须输出到正文**，⛔ 不许只藏在思考里。
8. **不要在没有复现步骤时瞎修症状**（P3 挂音属于这类，用户说了搁置）。

## 一句话验收

回归「通过数 == 共数」· PnR `0 setup / 0 hold` + 全门 OK + `P0-29` 报 14 条 · 位流产出 · **上板可验**。

---
