hokuu1102/Gowin2026-PolySynth/files/00-总览/交接文档-20260930.md

# 交接文档（2026-09-30）

> **定位**：⭐ 本项目（FPGA2026 · Tang Console 60K / Gowin GW5AT-LV60PG484AC1）**FPGA 侧**的交接。
> ⭐ 读完本文即可接手，⛔ 不需要翻旧对话。
> ⚠️ **本文所有"改动"一律【待上板验证】** —— ⛔ 没有任何一条可以写成"已修/已解决"。
> 📌 配套：`files/00-总览/未完成工作总账.md`（唯一待办入口）· `files/20-代码/方案与实现缺口审计.md`（缺口全景）

---

## 〇、状态快照（2026-09-30 12:41 核实）

| 项 | 值 |
|---|---|
| ⭐ **主树 HEAD** | `2801f11` — `Revert "新增：起始音（base note 八度档）+ 实时变调…"` |
| ⭐ **`origin/main`** | `7863b40` — `looper 事件通路改造与鼓机收尾（待上板验证）` |
| ⭐ **领先 `origin/main`** | **34 个提交**（⛔ **未 push**） |
| ⭐ **工作区** | 仅 `sim/evidence/*` 与两个 `_scratch_*` 未跟踪目录 |
| ⭐ **在跑** | `gw_sh 28860`（12:37:27 起，是 `pwsh-960` 那次「无变调版重建」） |
| ⭐ **stepB worktree** | `C:\Users\hokuu\Desktop\FPGA\FPGA2026-stepB` @ `19bcef2` `[step/B-timing]` |

---

## 一、🔴 当前最重要的处境

### 1.1 用户上板反馈（本会话核心事实）

| 版本 | 时间 | 用户听到的 |
|---|---|---|
| `AE_met_54p8` | 09:33 | ✅ **音高正常**（只报：节拍器偏小 · 回放节拍对不上 · 回放没拖尾） |
| `AG_drum_2b` | 10:21 | ✅ **音高正常**（只报 loop 的两条） |
| `AH_met_tail_pool` | 11:14 | 🔴 **音高错乱 / 哒哒声 / 按键不通** |
| `AJ_timing_ok_b2156d6` | 12:21 | 🔴 **串键 / 音高错乱 / 按键不通**（⭐ 板 2 同样错乱） |

⭐ **关键观察**：⭐ 用户明确说 ⭐ **"⭐ 板 2 按键有声音但也是错乱的"** ✅
⇒ ⭐ 说明是 **全局性**问题，⛔ **不是**接线/标定/单板问题。

### 1.2 ⭐⭐ 用户的硬性指示（必须遵守）

> ⭐ **"不要一下改完，现在逻辑全部混乱了，从正常的版本一点一点推进"**

⇒ ⭐ 现在的路线 = ⭐ **步进**：⭐ **每步只加一件事** ＋ ⭐ **一个 `.fs`** ＋ ⭐ **上板听一次** ＋ ⭐ **再走下一步** ✅
⇒ ⛔ **禁止**再把一堆改动合在一起出 `.fs`。

### 1.3 ⭐ 基准（已核实的"正常版本"）

| 项 | 值 |
|---|---|
| ⭐ **基准提交** | ⭐ **`9ccf742`** |
| ⭐ **基准 `.fs`** | ⭐ `build\bitstreams\AG_drum_2b.fs`（10:21） |
| ⭐ **基准含** | A1/A2/A3' ＋ 鼓机 4 类 ＋ 串口 `'D'` ＋ 2a 噪声表 ＋ 2b 音高包络 ＋ K-169 ＋ `on_open_r` |
| ⭐ **基准不含** | 小节对齐 · 尾音修复 · 节拍器音量 · **变调** · 池判据 · **时序修复** · pins3 · 新鼓点 |

---

## 二、⭐⭐ 两个头号嫌疑

### 2.1 ⚠️ 方法教训（⭐ 先看这条，⛔ 否则会得出错误结论）

🔴 **判断"某改动是否还在生效"⛔ 不能用 `git merge-base --is-ancestor`** ✅

- ⭐ 它只能说明"⭐ 该提交在**历史**里" ✅，⛔ **不能说明"⭐ 它的改动还在不在"** —— ⭐ revert 之后**祖先关系永远成立** ⚠️
- ⭐ **正确做法**：⭐ 看 ⭐ **文件内容**（⭐ 该符号还在不在 ✅）⭐ 或 ⭐ **是否已有 revert 提交**（⭐ 时间 vs `.fs` 时间 ✅）
- ⭐ 本会话我因此**一度得出错误结论**（⭐ 误判"`AJ` 里变调和池判据都不在" ❌）⇒ ⭐ **请勿重犯** ✅

### 2.2 ⭐ 按"⭐ 生效状态"⭐ 的对照表（⭐ 这是判定的唯一正确口径）

| 版本 | 时间 | **变调** | **池判据按来源** | 时序修复 | 上板结果 |
|---|---|---|---|---|---|
| `AE_met_54p8` | 09:33 | 无 | 无 | 无 | ✅ 音高正常 |
| `AG_drum_2b` | 10:21 | 无 | 无 | 无 | ✅ 音高正常 |
| `AH_met_tail_pool` | 11:14 | **有** | **有** | 无 | 🔴 错乱 |
| `AJ_timing_ok_b2156d6` | 12:21 | **有** | 无（`3527f6d` 11:26 已撤） | **有** | 🔴 串键/错乱 |

⇒ ⭐⭐ **变调是"坏/好"两组的唯一公共因子** ✅ ⇒ ⭐ **头号嫌疑** ✅
⇒ ⭐ **时序修复（`478b4ae`）是 `AJ` 里唯一新进【分配器】的逻辑** ⚠️ ⇒ ⭐ **二号嫌疑** ✅

### 2.3 ⭐ 头号嫌疑：变调（`953333e`，10:08）

- ⭐ 它**只在 `note_manager` 的 `cur_inc` 锁存处乘一个比例** ＋ ⭐ `pitch_upd` 那一路
- ⭐ **头号假设**：⭐ `semi_ratio`（25 项 `2^(n/12)`，Q1.15 17 位）是用 ⭐ **`initial` 初始化**的表 ⚠️
  ⇒ ⭐ 若综合后**没被正确推断成 ROM**（⭐ 初始化值丢了/被清零 ✅）
  ⇒ ⭐ `ratio_eff` = **0 或垃圾值** ⇒ ⭐ **每个音的比例被乘成 ~0** ⇒ ⭐ **"音高错乱 ＋ 按键像不通"**（⭐ 音被压到听不见 ✅）
- ⚠️ ⭐ 当时那份分析**自己就标注过这条没验**：⭐ *"变调 ROM 只做了**弱验证** ⇒ **逐项核对 ROM 常量未做**"*
- ⭐ 其它候选：⭐ 复位值 ≠ 1.0（32768）· ⭐ 旁路条件在真机上不成立 · ⭐ 位宽/符号/饱和 · ⭐ `base_semi_o` 上电值非 0 · ⭐ `pitch_upd` 组合乘法器
- ⏳ 已派子代理 `e1f6c8ff` 查（⭐ 要求它 ⭐ **不许只读 RTL**，⭐ 必须查**综合后的网表/常量** ✅）

### 2.4 ⚠️ 二号嫌疑：时序修复改了分配器语义（`478b4ae`）

| ⭐ 改动 | ⚠️ 可疑之处 |
|---|---|
| ⭐ 入口给 `env_level_i`(512b)/`env_active_i`(32b) **打一拍** | ⭐ `same_hit[sg]` 的判定**用了 `env_active_i`** ⇒ ⭐ 现在看到的是**上一拍**的活动状态 ⚠️ |
| ⭐ 同轴重触发加 `ST_RETRIG` ＋ ⭐ 写译码改用**寄存的** `same_idx_r` | ⭐ 索引与当前事件**错开一拍** ⚠️ ⇒ ⭐ 可能写到**错误的 voice** = ⭐ **串键** ✅ |

⚠️ **但它⛔ 不能简单回滚** —— ⭐ 回滚就回到 ⭐ **42.094 MHz / 4517 setup 违例** 🔴（⭐ 那份根本不能用 ✅）
⇒ ⭐ 正确做法 = ⭐ **换一种【语义逐位等价】的时序修法** ✅

### 2.5 ⭐ 池判据按来源（`f18aa4a`）—— ⭐ 已被证伪，⭐ 但仍是真缺陷

- ⭐ **已回滚**（`3527f6d`，11:26）✅
- ⭐ **真实链仿真证伪**（⭐ 探针按 `top.v` 接法搬进仿真，⭐ 两规则并列同一 tb ✅）：
  - ⭐ `3'd3` 的**唯一生产者**是 `top.v:3294` 的 `.b_src_i(3'd3)`，⭐ 其 valid 只来自 `metronome`/`drum_gen`
  - ⭐ 手弹由 `seq_arb.v:171` 打 `SRC_LIVE=3'd0`，⭐ **逐跳都是 0** ✅
  - ⇒ ⭐ **改动对手弹透明** ✅ ⇒ ⭐ **解释不了上板现象** ✅
  - ⭐ 而 ⭐ **真正错的是【旧按轴规则】**：⭐ 它把**物理键 14/15** 送进只有 5 个 voice 的**保留池**并标成**鼓 voice** ⚠️
- ⚠️ ⭐ 但它确实引入一个**新的静默失效面**：⭐ `pool_mask` 从"永远有定义的 `cur_axis`"换成"可能没定义的 `cur_src`"且**无 X/Z 兜底** ⇒ ⭐ 判据为 `x` 时 `pool_mask` 全 `x` ⇒ ⭐ **事件被静默丢弃**（⭐ 实测：⭐ `note_src_i` 悬空 ⇒ **6/6 全丢** ✅）
- ⇒ ⭐ **需按台账 §26.3 的 a~f 判据安全重做**（⭐ 保留"按来源" ✅ ＋ ⭐ 消费者侧 X/Z 安全 ✅ ＋ ⭐ 同源派生 ✅ ＋ ⭐ 独立提交 ✅ ＋ ⭐ 随 ≥3% 余量的 PnR ✅）
   > ⚠️ **2026-10-01 更正**：⭐ 门槛已由 **5% 降到 3%**（⭐ 用户裁定）⇒ 判据改为 **`Fmax ≥ 51.5 MHz`**。
   > ⭐ 理由：⭐ 5% 的原始依据已被用户撤回（⭐ 那次 0.18% 上板异常是**代码 bug**，⛔ 非时序问题）；
   > ⭐ 当前实测 `52.372 MHz`（+4.744%）⭐ 在 3% 下通过。⚠️ **新增 UART 后必须重测并对比**。

---

## 三、时序（⭐ 已解决，⭐ 但必须写清）

### 3.1 病灶（⭐ 决定性诊断）

| 项 | 值 |
|---|---|
| ⭐ **25 条 setup 违例** | ⭐ **全部同源**：`u_envelope_bank/g_voice_envelope[23].u_adsr/env_level_o_10_s0/Q` → `u_note_manager/*/CE`（slack −3.756…−3.549） |
| ⭐ **延迟拆解** | ⭐ **逻辑仅 2.8 ns · 布线 20.7 ns** ⚠️ ⇒ ⭐ **布线/拥塞主导** |
| ⭐ **结构** | ⭐ `env_level_o`(16b) → OR 树 → `active_o` → `same_hit[sg]` → **32 路优先编码器** → **32 路写译码** → `CE` ⚠️ |
| ⭐ **扇出** | ⭐ 该 `CE` **同时驱动 32 个 voice 的全部数组寄存器** ⇒ ⭐ **约 4500 端点**（与 4517 违例吻合） |
| ⭐ **资源对比** | ⭐ 本次 Logic 46390 / Register 14799 vs ⭐ 通过版 45924 / 14602 ⇒ ⭐ **只差 1%** ⇒ ⭐ **是布局/布线劣化，⛔ 不是设计变大** |

### 3.2 修法（`478b4ae`）

1. ⭐ 模块入口给 `env_level_i`(512b)/`env_active_i`(32b) ⭐ **打一拍**（+544 FF）
2. ⭐ 同轴重触发加 `ST_RETRIG` 流水级 ＋ ⭐ 写译码改用**寄存的** `same_idx_r`
3. ⭐ 未动 `ts_scale` 组合乘法 ⇒ `tb_note_manager.sv:582` 的判据**无需修改**

### 3.3 结果

| 判据 | 修前 | **修后** |
|---|---|---|
| Setup 违例 | 🔴 4517 | ✅ **0** |
| Hold 违例 | ✅ 0 | ✅ **0** |
| **Fmax** | 🔴 42.094 MHz | ✅ **55.677 MHz（余量 +11.4%）** |
| Logic Level | 12 | ✅ **2** |
| 最差路径 | `adsr/env_level → note_manager/*/CE`（−3.756） | ⭐ 换成无关的 `u_i2s_tx/HP_BCK_s1`（slack **+2.039**） |

### 3.4 🔴 新硬规则（台账 §26.2）

> ⭐ **PnR 余量 < 3% 的 bitstream ⛔ 不许烧板**

- ⭐ **判据**：`sim/evidence/gowin_m0_timing.txt` ⭐ **0 setup / 0 hold** ⭐ **且** ⭐ Fmax **≥ 51.5 MHz**（⭐ 两条缺一不可 ✅）
   > ⚠️ **2026-10-01 更正**：⭐ 门槛已由 **5% 降到 3%**（⭐ 用户裁定）⇒ 判据改为 **`Fmax ≥ 51.5 MHz`**。
   > ⭐ 理由：⭐ 5% 的原始依据已被用户撤回（⭐ 那次 0.18% 上板异常是**代码 bug**，⛔ 非时序问题）；
   > ⭐ 当前实测 `52.372 MHz`（+4.744%）⭐ 在 3% 下通过。⚠️ **新增 UART 后必须重测并对比**。

- ⭐ 现场：⭐ 余量 **+0.18%**（⭐ 最差 slack **0.036 ns**）那颗被烧 ⇒ ⭐ 板子异常 ✅；⭐ 同树重跑 ⇒ ⭐ **42.094 MHz / 4517 违例** 🔴
- ⚠️ ⭐ "单次绿 ≠ 可上板" —— ⭐ 本项目 PnR 是**布局噪声主导**（⭐ 同源重跑差 **2~3 MHz** ✅）

---

## 四、⭐ 步进路线（⭐ 用户要求，⭐ 必须遵守）

```
⭐ 基准 9ccf742（AG_drum_2b.fs，⭐ 音高正常 ✅）
  ↓ ⭐ 步 B：只加【时序修复 478b4ae】  ← worktree FPGA2026-stepB @ 19bcef2，⭐ 已备好，⭐ 待编
  ↓ ⭐ 步 C：只加【变调 953333e】      ← ⭐ 头号嫌疑 ⇒ ⭐ 单独烧即可定性
  ↓ ⭐ 步 D：只加【looper 三条】       ← 小节对齐 9224341 ＋ 尾音 a408ca7 ＋ 节拍器音量 8e615fa
  ↓ ⭐ 步 E：只加【pins3 ＋ 新鼓点】   ← 板B撤回 ＋ VEL_AXIS_N=16 ＋ 6d1d60a
  ↓ ⭐ 步 F：只加【池判据重做】        ← 16 键全可用
```

### ⭐ 每步的硬判据（⭐ 缺一不可）

| ⭐ 判据 | ⭐ 值 |
|---|---|
| ⭐ 时序 | ⭐ `0 setup / 0 hold` ⭐ **且** ⭐ 余量 **≥3%**（Fmax ≥51.5 MHz） <br>⚠️ **2026-10-01 更正**：⭐ 门槛已由 **5% 降到 3%**（⭐ 用户裁定）⇒ 判据改为 **`Fmax ≥ 51.5 MHz`**。<br>⭐ 理由：⭐ 5% 的原始依据已被用户撤回（⭐ 那次 0.18% 上板异常是**代码 bug**，⛔ 非时序问题）；<br>⭐ 当前实测 `52.372 MHz`（+4.744%）⭐ 在 3% 下通过。⚠️ **新增 UART 后必须重测并对比**。 |
| ⭐ 回归 | ⭐ 全量回归 ⭐ **「通过数 == 共数」**（⭐ ⛔ 不要写死数字 —— 加一个 tb 这个数就变 ✅） |
| ⭐ `^FAIL:` | ⭐ **0** |
| ⭐ 交付 | ⭐ 达标才给用户烧 ✅ ＋ ⭐ 归档**文件名带基点 SHA** ＋ ⭐ 附 `.meta.txt` ✅ |

⭐ **每步只需用户回答一句**：⭐ **"音高正常 / 串键"** ✅ ⇒ ⭐ 据此定方向 ✅

---

## 五、`.fs` 对照表（⭐ 按"实际含什么"）

| `.fs` | 时间 | 变调 | 池判据 | 时序修复 | 用户反馈 |
|---|---|---|---|---|---|
| `AE_met_54p8.fs` | 09:33 | 无 | 无 | 无 | ✅ 音高正常（报了节拍器小/回放不对齐/没拖尾） |
| `AF_met_2b_score.fs` | 10:06 | 无 | 无 | 无 | — |
| `AG_drum_2b.fs` | 10:21 | 无 | 无 | 无 | ✅ 音高正常（报了 loop 两条） |
| `AH_met_tail_pool.fs` | 11:14 | 有 | 有 | 无 | 🔴 哒哒声/音高对不上 |
| `AJ_timing_ok_b2156d6.fs` | 12:21 | 有 | 无 | 有 | 🔴 串键/音高错乱（SHA256 `3EE49496…`） |

### ⭐ 归档命名新规（`L101`）

1. ⭐ **文件名带基点 SHA**（⭐ 例 `AJ_timing_ok_b2156d6.fs` ✅）
2. ⭐ 附 ⭐ **`.meta.txt`**（⭐ 写明：⭐ 基点 / ⭐ 时序 / ⭐ **含什么** / ⭐ **⛔ 不含什么** / ⭐ 构建时间 ✅）
3. ⭐ 交付上板时 ⭐ **同时给出"含哪些提交 / 不含哪些"** ✅

⚠️ ⭐ 教训：⭐ 曾把 `AG_drum_2b.fs`（⭐ 基点 `9ccf742` ✅）交给用户复验两个修复 ⚠️，⭐ 而那两个修复（⭐ 小节对齐 10:06 ＋ 尾音 10:39 ✅）**都不在它的基点里** ⇒ ⭐ 用户听到"⭐ 还是没好"⭐ 是必然的 ✅（⭐ 见 `L101` ✅）

---

## 六、硬件（⭐ 用户已拍板）

### 6.1 ⭐ ADC 片号映射（⭐ 权威）

| 片 | 用途 | MISO | CS |
|---|---|---|---|
| **片 0** | 左手板 1（已接） | `C15`（`J9 N3`） | `C14`（`N4`） |
| **片 1** | 左手板 2（本次联调） | **`B13`**（`J9 N5`） | **`C13`**（`N6`） |
| **片 2** | 右手板 A（暂不启动） | **`A14`**（`J9 N7`） | **`A13`**（`N8`） |
| 片 3~5 | 备用 | `B16`/`A16`/`A20` | `B15`/`A15`/`B20` |

- ⭐ 共享：⭐ `SCLK = E14`（`J9 N1`）· ⭐ `MOSI = E13`（`N2`）
- ⭐ 电源/地：⭐ `N11` / `N12` · ⭐ 板位选 LED：⭐ `led_oe_n[0]=B17`（板1）· `led_oe_n[1]=C17`（板2）
- ⭐ 右手板 A 拨弦：⭐ `TRIG_UP = E21` · `TRIG_DN = D21`（BANK2）
- ⚠️ **两份旧文档写"片 4 = 右手板 A（`N13/N14`）"是错的** ⇒ ⭐ **按它接线会没反应** ✅（⭐ 已在 2026-09-30 更正 ✅）

### 6.2 ⚠️ 上电顺序（⭐ 必须遵守）

⭐ **先插板，再上电** ✅
- ⭐ 片 1 未接时 MISO 被**内部上拉** ⇒ `raw = 4095` ⇒ ⭐ `autotare` 把 zero 记成 4095 ⇒ ⭐ **`pos ≡ 0`**（⭐ "不出声也不误触发"是**假象** ⚠️）
- ⭐ 若已上电才插板 ⇒ ⭐ **补发一次串口 `'T'`** ✅

### 6.3 ⭐ 其它已拍板项

| 项 | 状态 |
|---|---|
| ⭐ `RIGHT_ADC_ENABLE` | ⭐ **保持 0**（⭐ 右手板暂不启动 ✅）· ⚠️ 板 A 没接好前 ⛔ 不要改 1（⭐ 悬空 ⇒ 颤音拉满 ✅） |
| ⭐ **板 B** | ⭐ **取消原计划** ⇒ ⭐ 改**通用控制板**（⭐ 可能矩阵键盘，⭐ **键数/接口待定** ✅）⇒ ⭐ **不分配任何引脚** ✅ |
| ⭐ **OLED** | ⭐ **取消** ✅（⭐ 那 10 根引脚已撤回 ✅） |
| ⭐ **力度跟随** | ⭐ 已覆盖 **16 轴**（⭐ `VEL_AXIS_N` 8→16 ✅）· ⚠️ 代价：⭐ **单轴刷新率 164 → 328 µs** ⇒ ⭐ **用户已拍板接受** ✅（⛔ 不再考虑"每拍扫 2 轴" ✅） |
| ⭐ **JTAG 四根** | ⛔ **绝不能碰**（`TMS=T13` · `TDO=U13` · `TCK=V12` · `TDI=R13`，BANK12） |

### 6.4 ⭐ 串口

- ⭐ 波特率 ⭐ **500000**（8N1）· ⭐ 发 ⭐ **单个 ASCII 字符** ✅
- ⭐ 命令：⭐ `T S X P V M N R L C I` ＋ ⭐ **`B`**（节拍器开关）＋ ⭐ **`D`**（鼓机节奏型切换）＋ ⭐ **`F`/`G`**（±半音 —— ⚠️ **现已随变调一起回滚** ✅）

---

## 七、常用命令（⭐ 判据写全）

```powershell
# ⭐ 全量回归（~15 min）｜判据：⭐ 通过数 == 共数 且 ^FAIL: 计数 0
powershell -NoProfile -ExecutionPolicy Bypass -File sim\tb_all.ps1

# ⭐ 聚焦单 tb
powershell -NoProfile -ExecutionPolicy Bypass -File sim\tb_all.ps1 -Filter tb_note_manager

# ⭐ PnR（~10~40 min）｜判据：⭐ 0 setup / 0 hold 且 Fmax ≥51.5 MHz（余量 ≥3%）
powershell -NoProfile -ExecutionPolicy Bypass -File sim\gowin_build.ps1 -BuildTimeoutSec 3600

# ⭐ 烧录（⚠️ --operation_index 1 = 烧写；0 只读 ID，看着成功但没烧）
& "C:\Gowin\Gowin_V1.9.12.03_x64\Programmer\bin\programmer_cli.exe" `
  --device GW5AT-60B `
  --fsFile "<.fs 绝对路径>" `
  --operation_index 1 `
  --cable "USB Debugger A"
```

⭐ 结果文件：⭐ `sim/evidence/gowin_m0_timing.txt`（⭐ 时序 ✅）· ⭐ `sim/evidence/gowin_m0_rsc.xml`（⭐ 资源 ✅）· ⭐ `impl/pnr/Gowin2026.timing_paths`（⭐ 关键路径 ✅）
> ⚠️ **2026-10-01 更正**：⭐ 门槛已由 **5% 降到 3%**（⭐ 用户裁定）⇒ 判据改为 **`Fmax ≥ 51.5 MHz`**。
> ⭐ 理由：⭐ 5% 的原始依据已被用户撤回（⭐ 那次 0.18% 上板异常是**代码 bug**，⛔ 非时序问题）；
> ⭐ 当前实测 `52.372 MHz`（+4.744%）⭐ 在 3% 下通过。⚠️ **新增 UART 后必须重测并对比**。

---

## 八、纪律 / 坑（⭐ 本会话新增的）

| ⭐ # | ⭐ 纪律 |
|---|---|
| ⭐ **1** | 🔴 **后台重活必须从【主线程】起** —— ⭐ 子代理一结束，⭐ 它的后台任务就被带走 ✅（⭐ 本次实测：⭐ 时序子代理的回归被杀，⭐ 重起才拿到结果 ✅） |
| ⭐ **2** | ⭐ **⛔ PnR 与全量回归不并行**（⭐ 用户硬要求 ✅）· ⭐ **一次一个重活** ✅ |
| ⭐ **3** | ⭐ 改 `rtl/`/`constr/` 时 ⛔ **不要与正在跑的 PnR/回归重叠** ✅ |
| ⭐ **4** | ⭐ **判断改动是否生效 ⛔ 不用 `git merge-base --is-ancestor`** ✅（⭐ 见 §2.1 ✅） |
| ⭐ **5** | ⭐ **`sim/evidence/*.log` 会让 cherry-pick 报"uncommitted changes"** ⇒ ⭐ 先 `git add sim/evidence && git commit` 再挑 ✅；⭐ 冲突时证据日志一律 `--ours` ✅ |
| ⭐ **6** | ⭐ **一次只加一个改动**（⭐ 用户指示 ✅）· ⭐ 每步一个 `.fs` ＋ ⭐ 上板一次 ✅ |
| ⭐ **7** | ⭐ **余量 <3% ⛔ 不许烧** ✅（⭐ 新硬规则 ✅） <br>⚠️ **2026-10-01 更正**：⭐ 门槛已由 **5% 降到 3%**（⭐ 用户裁定）⇒ 判据改为 **`Fmax ≥ 51.5 MHz`**。<br>⭐ 理由：⭐ 5% 的原始依据已被用户撤回（⭐ 那次 0.18% 上板异常是**代码 bug**，⛔ 非时序问题）；<br>⭐ 当前实测 `52.372 MHz`（+4.744%）⭐ 在 3% 下通过。⚠️ **新增 UART 后必须重测并对比**。 |
| ⭐ **8** | ⭐ **`.ps1` 一律 UTF-8 with BOM 或纯 ASCII** ✅；⭐ 编辑 `.md`/源码 ⛔ 不用"读文本+写文本"整体重写（⭐ 会翻搅行尾 ✅），⭐ 用 `edit` 工具 ✅ |
| ⭐ **9** | ⭐ 经验库已录：⭐ **`L101`**（上板前核对 `.fs` 与提交的对应关系 ✅）· ⭐ **`L102`**（"有声判据"抓不到整链跑调 ＋ 余量 <5% 不许烧 ✅）· ⭐ **待录**：⭐ 判断改动是否生效的正确方法 ✅ <br>⚠️ **2026-10-01 更正**：⭐ 门槛已由 **5% 降到 3%**（⭐ 用户裁定）⇒ 判据改为 **`Fmax ≥ 51.5 MHz`**；<br>⭐ 本条为 2026-09-30 的历史记录，⭐ 原文保留。⚠️ **新增 UART 后必须重测并对比**。 |

---

## 九、待办（⭐ 我们范围内的）

### 9.1 立即

1. ⭐ **步 B ~ 步 F**（⭐ 见 §四 ✅）—— ⭐ 步 B 已备好（`19bcef2`），⭐ **待编 ＋ 核时序 ＋ 归档 ＋ 交用户烧** ✅

### 9.2 变调真因（⭐ 头号嫌疑）

- ⭐ 头号假设：⭐ `semi_ratio` 用 `initial` 初始化 ⇒ ⭐ 综合后没被正确推断成 ROM ⇒ ⭐ 比例变 0/垃圾 ✅
- ⏳ 子代理 `e1f6c8ff` 在查（⭐ 要求它查**综合后的网表/常量**，⛔ 不许只读 RTL ✅）
- ⭐ 要求补判据：⭐ **"上电后第一颗音，⭐ 在没发任何命令时 `cur_inc` 必须与 `head_inc` 逐位相同"** ✅

### 9.3 判据盲区（台账 §26.4）

🔴 ⭐ **全套 tb 没有任何音高/数值判据** —— ⭐ `tb_top_sound`/`tb_e2e_key_to_sound` 只断言"⭐ 有声音 / `HP_DIN` 翻转" ⚠️
⇒ ⭐ **一条整体跑调的链路也能 103/103 全绿** ✅
⇒ ⭐ 必须补：⭐ **"键 k ⇒ `phase_inc == axis_map(k)` × 变调比"** ＋ ⭐ **"不许串键"**（⭐ 按 A 轴再按 B 轴并按住 ⇒ ⭐ 各轴 voice 各带本轴音高/力度 ✅）

### 9.4 其它

| ⭐ 项 | ⭐ 说明 |
|---|---|
| ⭐ 池判据安全重做 | ⭐ 台账 §26.3 的 a~f 判据（⭐ 16 键全可用 ✅） |
| ⭐ 收尾清理 | ⭐ 「_scratch_k169/」（历史引用，当前未收录） · ⭐ 「_scratch_metfix/」（历史引用，当前未收录） · ⭐ 24 个 worktree ⚠️ · ⭐ `%TEMP%\fpga2026_mut\` |
| ⭐ push | ⭐ 34 个提交 ⭐ **压成 1 个** ✅（⭐ 需用户同意 ＋ ⭐ `pre-squash` tag ＋ ⭐ bundle 备份 ✅） |

### 9.5 ⛔ 不是我们的（⭐ 不要推进）

⭐ **LED 指引**（丙）· ⭐ **HDMI**（乙）· ⭐ **效果器**（队友，⭐ 归档在 `build\fx_parked\` ✅）· ⭐ **串口屏控件**（丙）· ⭐ **`U-22`**（乙）· ⭐ **硬件建模/踏板/拓展板**（用户）✅

---

## 十、⚠️ 最后提醒

1. ⭐ 本文所有改动 ⭐ **一律待上板验证** ✅ —— ⛔ **不要对用户说"已修好"** ✅
2. ⭐ 用户能上板时 ⭐ **优先做需要上板的事** ✅；⭐ 不能上板时 ⭐ 做不需要上板的事（⭐ 代码/文档/判据 ✅）
3. ⭐ **有问题先列表问用户**（⭐ 攒着一起问，⛔ 不要因为等回答而阻塞进程 ✅）
4. ⭐ 每次给用户的结论 ⭐ **都要有判据/数据支撑**（⭐ ⛔ 不要"看起来正常" ✅）
---

# 📦 ESP32 线 · 交接文档（2026-09-30）

> ⚠️ **合并说明（⭐ 2026-10-01）**：⭐ 本文与上面的「交接文档（2026-09-30）」**原本同名**
> （⭐ 两条线各自建了 `files/00-总览/交接文档-20260930.md` ⚠️）⇒ ⭐ 合 PR 时冲突 ✅
> ⇒ ⭐ **两份内容全部保留**：⭐ **上面是【FPGA 线】的** · ⭐ **下面是【ESP32 线】的** ✅

> **交付对象**：⭐ **接手 ESP32 通路的下一个会话**
> **工作目录**：⭐ **`C:\Users\hokuu\Desktop\FPGA\FPGA2026-esp32`**（⚠️ **不是** `FPGA2026`）
> **分支**：`feat/s3-ble`
> 🔴🔴 **2026-09-30 更正**：⚠️ 本节原写「`@ b998e32`（⭐ **本地领先远端 2 个**）」——
> 🔴 **该哈希与那个数字【都已作废】**（⚠️ 此后又落了多个提交）。
> ⭐ **以 `git status -sb` 为准**（⛔ 本文不再写死哈希/领先数）。
> **建立时间**：2026-09-30

---

## 〇、⭐⭐ 三句话现状

| # | ⭐ |
|---|---|
| **1** | ⭐⭐ **ESP32 已经上过机器了，而且跑通了** —— 能广播、能连接、能收发数据（`ble_rx=9` / `mtu=517`） |
| **2** | 🔴 **上机第一晚抓到 4 个真缺陷，全部定位并修复**（⭐ 看门狗 + BLE 广播） |
| **3** | ⭐ **完整灌数据验收已完成** —— 🔴🔴 **2026-09-30 更正**：⚠️ 本节原写「下一步是"完整灌数据验收" —— 卡在 PC 端」<br>🔴 **该断言已作废**：⭐ 已改用 **`bleak` 直连**（`esp32/tools/send_frames_ble.py`）**绕开虚拟串口** ⇒<br>⭐ **205 帧验收已跑完**，且 ⭐ **反向通路也打通了**（见 §一之一） |

---

## 〇之二、⭐⭐ 2026-09-30 / 2026-10-01 新增（⭐ 本节原【不存在】，全部为当日新事实）

> 🔴🔴 **2026-10-01 第二轮审计**：⚠️ 第 **4**、**5** 行是第一轮写的，⭐ 当夜 `0xABF3` 加了起播/停止、`0xABF4` 扩成六组 ⇒ 🔴 **已就地更正**；⭐ 另补第 **10**~**15** 行。

| # | ⭐ 事实 | 证据 |
|---|---|---|
| **1** | ⭐ **波特率 = `500000`**（🔴 **不是 `1000000`**） | `esp32/ble/main/ble_config.h` `BLE_BAUD 500000`·`esp32/uart_test/main/uart_test_main.c` `TEST_BAUD 500000`·`esp32/bridge/main/bridge_config.h` `BRIDGE_BAUD 500000`；FPGA 侧 2026-09-24 降档 |
| **2** | ⭐⭐ **反向通路（FPGA→ESP32→BLE→PC）已打通** | ⭐ **2000 字节 round-trip 逐字节一致**；`esp32/evidence/反向通路验收-ESP32侧-20260930.md` |
| **3** | ⭐ **上行环形缓冲已存在** | `esp32/ble/main/up_ring.c/.h`，**160 KB in PSRAM**；语义：未订阅 ⇒ **蓄水**、已订阅 ⇒ **放水**、满 ⇒ **拒绝新数据（保留最早的）** |
| **4** | ⭐⭐ **`0xABF3`(CMD) 有【四个】命令**：`0x01` 清池 · `0x02` 状态上报 · ⭐ **`0x03` 起播** · ⭐ **`0x04` 停止** | `esp32/ble/main/ble_main.c` 的 `if (h == s_handle_cmd)` 块 ⭐ `case 0x01`/`0x02`/`0x03`/`0x04`（⭐ 截至提交 `35036bf` 在 `:606` / `:611` / `:629` / `:634`；⚠️ **行号会漂，⛔ 别写死**）；⭐ 未知命令**计数不吞**（`cmd_unk`）<br>🔴🔴 **2026-10-01 更正**：⚠️ 原写「`0x01` 清池 · `0x02` 状态上报；⚠️ **故意不做 start/stop**（架构未定）」⇒ 🔴 **已作废**（⭐ 用户 2026-09-30 已裁定走模式 B、起播键在 ESP32，`files/20-代码/用户裁定结果-20260930.md` §〇） |
| **5** | ⭐⭐ **`0xABF4`(STAT) 返回【六组】**：`V1 mode=` · `pool=` · `ring=` · `ble=` · `uart=` · `frame=` · `cmd=`<br>⭐ **`V1` 行带 `req=`（快照序号）/ `up=`（生成时刻）** ⇒ ⭐ **陈旧【可判定】**（提交 `35036bf`）<br>🔴 **但它仍是【拉取快照】**：⭐ **只有先发 `CMD 0x02` 才刷新**（`cmd_report_status()` **只**被 `case 0x02` 调用，⭐ 截至 `35036bf` 在 `:613`）；⚠️ 不发就直读 = 上一次的内容（⭐ 能判定，⚠️ **不自动刷新**）<br>🔴 **尺寸警告**：⭐ 代表性样本 **261 B** > `char buf[256]`（`ble_main.c:352`）⇒ ⚠️ **可能截断尾部（`cmd=` 组）** | `esp32/ble/main/ble_main.c:336` `cmd_report_status()`（六条 `snprintf` `:378`~`:390`）；缓冲区 **256 B**（`gatt_svc.c:99`）；属性**只读**（`ESP_GATT_PERM_READ` + `RSP_BY_APP`，`gatt_svc.c:180`~`:182`）<br>🔴🔴 **2026-10-01 更正**：⚠️ 原写「实测返回 `pool=0/18204 sent=0 ovf=0\|ring=0 u_drop=0/0`」⇒ 🔴 **旧的三组短格式，已作废** |
| **6** | ⭐ **一键端到端工具** | `esp32/tools/e2e_accept.py`（⭐ 清池 → BLE 灌 → 起播 → 抓包 → 判据表；⭐ 通过退出码 0） |
| **7** | ⭐ **模式 B"放水"实测正确** | `rate=1919 tick/s`（期望 1920）、`sent=200/200` |
| **8** | ⭐ **串口起播触发** | UART1 RX（`GPIO18`）上的单字符 `S`/`X`/`R`，⭐ `ble_main.c` 的 `task_uart_to_ble` 解析 |
| **9** | 🔴 **按键脚是 `GPIO6`** | `esp32/ble/main/ble_config.h` `BLE_BTN_GPIO 6`（⛔ **不是 `GPIO0`**） |
| **10** | 🔴🔴 **板载 WS2812 指示灯【已关闭】** | `esp32/ble/main/ble_config.h:494` `WS2812_ENABLE 0` · `:502` `WS2812_CLEAR_ON_BOOT 1` ⇒ ⭐ 每次开机发一次全 0 清锁存，之后**永不点亮**；⚠️ 用户 2026-10-01 裁定「安全第一」（`files/20-代码/今晚任务书-20261001.md:38`）<br>🔴 **2026-09-30 夜那版"连上 BLE 亮一下"已作废**；⭐ 硬件上 WS2812 = `GPIO48`，⚠️ 且板上 `R17` 出厂断开、须短接跳线（`esp32/ble/main/ws2812.h`） |
| **11** | ⭐ **flash = 16 MB**（🔴 不是 2 MB） | `esp32/ble/sdkconfig.defaults:40-41` `CONFIG_ESPTOOLPY_FLASHSIZE_16MB=y` / `"16MB"` |
| **12** | ⭐ **上行是【透明字节流】** ⇒ 68 B 表帧原样穿过，⛔ 零固件改动 | `esp32/ble/main/ble_main.c:990` `up_ring_pop()` → `:976` `esp_ble_gatts_send_indicate()` |
| **13** | ⭐⭐ **上行帧长【按类型不同】**：音符类 **14 B**、表同步（`0x10`）**68 B** | `esp32/tools/evt2midi/frame_format.py` `FRAME_LEN_BY_TYPE`（🔴 ⛔ 不要用固定 14 B 切流） |
| **14** | ⭐ **新增三个 PC 侧工具** | ⭐ `esp32/tools/evt2midi/`（`rec_upstream.py` 录 → `evt2midi.py` 转 → `.mid`；`frame_format.py` 帧布局）· ⭐ `esp32/tools/stat_read.py`（发 `CMD 0x02` 读 `0xABF4` 逐字段核对）· ⭐ `esp32/tools/regress_live.py`（真机回归：命令集 + 上行蓄水/放水） |
| **15** | ⭐ **10 个验收/回归工具全部有 `--selftest`**（⭐ 纯离线） | `uart_rx_check` · `pool_pace_check` · `pool_math_check` · `uart_timing_check` · `trigger_and_capture` · `read_log` · `stat_read` · `e2e_accept` · `regress_live` · ⭐ **`rec_upstream`**<br>⭐ 提交 `764ee0f`：「`rec_upstream.py` 补 `--selftest`（⭐ 全部 10 个工具现在都有）」—— 🔴🔴 **2026-10-01 更正**：⚠️ 本表初稿写「8 个工具都有」+「⚠️ `rec_upstream.py` 仍没有」⇒ 🔴 **该断言在审计进行中即被推翻**（⭐ 作者读到后**当场补上**）⇒ ⭐ **现值 = 10 个全有**；⭐ 非空洞性由**变异测试 22/22 判红**证明（`files/20-代码/今晚任务书-20261001.md:67`；⭐ 全量 **275 项判据 / 0 RED** 见 `:81`） |

---

## 一、⭐⭐ 已完成（⭐ 全部有实测证据）

### 1.1 ⭐ 上机实测结果（⭐ 2026-09-24，ESP32-S3-DevKitC-1 @ `COM29`）

| 检查项 | ⭐ 实测 | |
|---|---|---|
| 芯片 | `ESP32-S3 (QFN56) (revision v0.2)` | ✅ |
| **PSRAM** | **`Embedded PSRAM 8MB`**（八线 octal，`good-die Pass`） | ✅ |
| **模式** | `mode = B / POOL`（⭐ 默认就是水池） | ✅ |
| **波特率** | ⭐ **`uart=1 baud=500000 tx=GPIO17 rx=GPIO18 frame=9B`** | ✅ |
| **水池** | `pool=163840 B in PSRAM` = **18204 帧**（⭐ 整曲 104 KB 放得下） | ✅ |
| **GATT 属性表** | `attr table created OK`，`0xABF0/1/2/3/4` 全就位 | ✅ |
| **体积** | `0xc1250`（⭐ 与参考值**精确一致** ⇒ 模式开关生效） | ✅ |
| **BLE 广播** | `advertising as "FPGA2026-Synth"` | ✅ |
| **BLE 连接** | `BLE CONNECTED conn_id=0` | ✅ |
| **MTU** | ⭐ **`mtu=517`** | ✅ |
| **帧解析** | ⭐ **`rst=1`、`unk=0`** —— 全 `A5` 被正确识别为复位帧 | ✅ |

> 📌 **日志存证**：`esp32/evidence/bootlog-COM29-*.log`（⭐ 两份：修复前 / 修复后）

### 1.2 ⭐ 修掉的 4 个真缺陷

| # | 缺陷 | ⭐ 根因 | 提交 |
|---|---|---|---|
| **1** | 🔴 **看门狗必然触发**（上电 5 秒） | 🔴 **`pdMS_TO_TICKS()` 是整数除法** —— `CONFIG_FREERTOS_HZ=100` ⇒ **`pdMS_TO_TICKS(1)` = 0**、`(2)` 也 = 0 ⇒ 任务变成**无条件空转** | `a310700` |
| **2~4** | 🔴 **BLE 广播从未启动** | ⭐ **三个缺陷叠加**（⚠️ 互相掩盖 ⇒ **必须全修才见效**） | `c7d03ad` |

> ⭐ **完整分析**（含栈回溯、逐条根因、**失败路径**）：
> `files/20-代码/ESP32上机实测问题分析-20260924.md`

### 1.3 ⭐ 已备好的工具与文档

| 项 | ⭐ 位置 |
|---|---|
| ⭐ **上机操作指南** | `esp32/上机指南.md`（⭐ **傻瓜步骤 + 预期现象**） |
| ⭐ **PC 侧 BLE 直连灌数据** | `esp32/tools/send_frames_ble.py`（⭐ **绕开虚拟串口**） |
| PC 侧串口灌数据 | `esp32/tools/send_frames.py`（⭐ `--selftest` 8/8 通过） |
| ⭐ **问题分析** | `files/20-代码/ESP32上机实测问题分析-20260924.md` |
| 工程总览（两版区别） | `esp32/README.md` |
| 串口屏三件套 | `esp32/串口屏控件清单.md` / `上机说明` / `指令表` |

---

## 二、⭐⭐ 当前状态（⭐ 已核实）

| 项 | ⭐ 值 |
|---|---|
| **分支** | `feat/s3-ble`（⚠️ **具体 HEAD 以 `git log -1` 为准**） |
| **远端** | ⭐ **以 `git status -sb` 为准**（⚠️ 原写"本地领先 2 个"🔴 **已作废** —— 那是易失数字） |
| ⭐ **`origin/main`** | ✅ **已包含 BLE 版**（⭐ 队友把分支合进去了） |
| **工作区** | ⭐ **以 `git status --short` 为准** |
| **两版固件** | ✅ BLE `0xc1250` / SPP `0xa4b30`（零 error 零 warning） |

---

## 三、🔴 下一步（⭐ 按优先级）

| # | 事项 | 优先级 | ⭐ 说明 |
|---|---|---|---|
| **1** | ✅ **打通 PC 端自动化灌数据** | ✅ **已完成** | 🔴🔴 **2026-09-30 更正**：⭐ 本节原标"下一步/高" —— **已完成**：⭐ 用 **`bleak` 直连**（`esp32/tools/send_frames_ble.py`） |
| **2** | ✅ **跑完整 205 帧验收** | ✅ **已完成** | ⭐ 判据 `total=200` / `tf=1` / `rst=4` / `unk=0` / `ovf=0` / `mismatch=0` —— ⭐ 证据 `esp32/evidence/205帧BLE验收报告-20260930.md` |
| **3** | ✅ **`BLE_TX_GAP_MS=2` 看门狗风险** | ✅ **已处理** | 🔴🔴 **2026-09-30 更正**：⚠️ 原文写"本轮**未改**"⇒ 🔴 **已改**（⭐ 它在 `HZ=100` 下塌成 `vTaskDelay(0)`，⭐ 是反向通路三条缺陷之一） |
| **4** | 串口屏接线 + **5V 供电** | ⚠️ 中 | ⚠️ 上机时**屏未接**（`hmi: no 0x88 ACK` 是"没接屏"的**正常降级**） |
| **5** | ✅ **`flash` 2 MB → 16 MB 映像头** | ✅ **已完成** | 🔴🔴 **2026-10-01 更正**：⚠️ 原写「`flash` 2 MB 映像头上限 · 🔵 低 · ⚠️ 实为 16 MB，但映像头写 2 MB（⛔ 当前不阻塞，⚠️ 将来放曲谱/字库会浪费 14 MB）」⇒ 🔴 **该待办已关闭**。⭐ 现值 = **16 MB**（`esp32/ble/sdkconfig.defaults:40-41` `CONFIG_ESPTOOLPY_FLASHSIZE_16MB=y` / `"16MB"`；⭐ 落地记录 `files/20-代码/今晚任务书-20260930.md:75`，⭐ 分区表未动，仍 `partitions_singleapp`） |

---

## 四、⚠️ 当前卡点（⭐ 先说清楚，⛔ 免得白查固件）

> ✅ **本节【已于 2026-09-30 解除】**
> 🔴🔴 **2026-09-30 更正**：⚠️ 本节原写「"完整 205 帧灌数据验收未完成" —— 卡在 PC 端虚拟串口，⛔ 不是固件问题」。
> 🔴 **该卡点已不存在**：⭐ 改用 **`bleak` 直连**（`esp32/tools/send_frames_ble.py`）**绕开虚拟串口** ⇒
> ⭐ **205 帧验收已跑完**，⭐ 且 **`esp32/tools/e2e_accept.py` 一键端到端**也已可用（⭐ 通过退出码 0）。
> ⚠️ **保留原文以供追溯**（⛔ 不删历史）：

| 现象（⚠️ **历史**） | ⭐ 说明 |
|---|---|
| ⚠️ `ble-serial-bridge`（虚拟 COM）**未完全打通** | ⚠️ 见 `ESP32上机实测问题分析` §5.5 |
| ⭐ **对策** | ⭐ **改用 `bleak` 直连**（⭐ 工具已写：`send_frames_ble.py`）⇒ ✅ **已落地生效** |

---

## 五、🔴 环境与工具坑（⭐ 已踩过，⛔ 别重踩）

| # | 坑 | ⭐ 对策 |
|---|---|---|
| **1** | 🔴 **`idf.py monitor` 是交互式终端**，脚本抓不到日志 | ⭐ 用**重定向**或**串口读取**（⛔ 不要 `monitor` + 管道） |
| **2** | 🔴 **端口号会漂移**（⛔ 不能写死 `COM29`） | ⭐ 每次**先查实际口号** |
| **3** | ⚠️ **串口句柄要及时释放** | ⚠️ 否则下次打不开 |
| **4** | 🔴 **扫引脚时⛔ 不要碰 `GPIO38/48`** | ⚠️ 那是 **RGB LED / USB** 相关 |
| **5** | ⭐ **`pdMS_TO_TICKS()` 小值会塌成 0** | ⭐ **1 tick = 10 ms**（`HZ=100`）⇒ ⚠️ **任何 `pdMS_TO_TICKS(1..9)` 都是 0** |

---

## 六、⭐⭐ 诊断方法论（⭐ 本轮最有价值的收获）

| # | 方法 | ⭐ 用途 |
|---|---|---|
| **1** | ⭐⭐ **烧 IDF 官方例子做对照** | **区分"我们的代码问题" vs "板子/IDF/环境问题"** —— ⭐ **最高效的一步** |
| **2** | ⭐ **完整 diff `sdkconfig`**（官方 vs 我们） | ⛔ 不要只盯自己怀疑的那一项 |
| **3** | ⭐ **逐行对照官方例子的源码** | 找"**官方有、我们没有**"的调用 |
| **4** | **引脚自证**（输入+上下拉，读电平） | 判断某脚**有无外部连接** |
| **5** | **本机自环**（TX 短接 RX） | 验证 UART/引脚**本身**是否可用 |
| **6** | **引脚定位器**（轮流在某脚发标识） | ⭐ 反推"**哪个物理针 = 哪个 GPIO**"，绕开丝印 |
| **7** | **RX 定位器**（全脚扫描） | ⭐ 反推"**对端数据进了哪个脚**" |
| **8** | **GAP 回调打 event 编号** | ⭐ 一眼看出事件常量对不对 |

> ⭐ 方法 4~7 的**代码是一次性诊断工具**（⛔ 不入库），⭐ **但方法值得记**。

---

## 七、🔴 边界（⭐ 必须知道）

| # | 说明 |
|---|---|
| **1** | ⚠️ **`play_seq` 在 FPGA 的 `top.v` 里仍未例化** ⇒ 🔴 **即便 ESP32 全对，FPGA 也不会出声** |
| **2** | ✅ **完整曲谱灌数据【已验证】** —— 🔴🔴 **2026-09-30 更正**：⚠️ 原文写"尚未验证 —— ⭐ 只验证了 9 字节的收发"⇒ 🔴 **已作废**：⭐ **205 帧验收已跑完**（`esp32/evidence/205帧BLE验收报告-20260930.md`），⭐ 且 **2000 字节反向 round-trip 逐字节一致** |
| **3** | ⚠️ **串口屏未接**（⭐ 屏的显示/变色**尚未与 ESP32 联调过**） |
| **4** | ⭐ **未推提交数**：🔴 **以 `git status -sb` 的 `ahead N` 为准**（⚠️ 原写"本地领先远端 2 个提交"🔴 **已作废** —— 那是易失数字，⛔ 不要再写死） |

---

## 八、⭐ 三条硬约束（⭐ 别越界）

| # | 约束 |
|---|---|
| **1** | 🔴 **FPGA 侧在另一条线**（`rtl/` `constr/` `tb/` `sim/` `tools/`）⇒ ⛔ **不改**（⭐ 只读） |
| **2** | ⭐ **本线只做 `esp32/`** |
| **3** | ⭐ **工作目录是 `FPGA2026-esp32`**（⚠️ **不是** `FPGA2026`）—— ⚠️ **两个都开着，最容易搞混** |

---

## 附 · 关联文档（⭐ 按读取顺序）

| # | 想看什么 | 去哪 |
|---|---|---|
| **1** | ⭐⭐ **上机操作步骤** | `esp32/上机指南.md` |
| **2** | ⭐⭐ **上机问题分析（4 个缺陷）** | `files/20-代码/ESP32上机实测问题分析-20260924.md` |
| **3** | ⭐ 工程总览（两版区别 + 三种帧格式） | `esp32/README.md` |
| **4** | ⭐ 串口屏三件套 | `esp32/串口屏控件清单.md` 等 |
| **5** | ⭐ 对接点与联调清单 | `files/20-代码/ESP32侧接续准备-20260923.md` |
| **6** | ⭐ 通路主文档（9N 对齐为什么关键） | `files/20-代码/ESP32通路总体架构-20260922.md` |
| **7** | ⚠️ 上一份断点（⭐ 部分已过时） | `files/20-代码/ESP32线当前断点-20260924.md` |
