hokuu1102/Gowin2026-PolySynth/files/00-总览/国庆安排-PCB与模型-20261001.md

# 🗓️ 国庆安排 · **PCB 与模型**（2026-10-01 夜版 · ⭐ v2 已按盘点报告更正）

> **范围**：⭐ **只排 PCB 与 3D 模型两条线**（⭐ FPGA 线见 `files/00-总览/计划推进表-20261001.md`）
> **前提（⭐ 用户已定，⛔ 不再问）**：
> ⭐ 左手板 ＋ 右手板 A **已打样并焊接完成** ✅ · ⭐ 国庆做 **Console 拓展板 ＋ 通用控制板** ·
> ⭐ 模型做 **键帽 / 右手区结构件 / 整机外壳面板 / PCB 3D 装配核对** · ⭐ **嘉立创打板** ·
> ⭐ **3D 打印等收假回实验室打**
>
> ⚠️ **v2 更正了 v1（本文档初版）的两处判断**（⭐ 见 §一-A1 与 §二-B1 的 🔴 标记）：
> ① **拓展板的"板级定义"并没有冻结** —— 现行文档全是换板前口径 ⇒ ⛔ 不是"今晚就能开画"；
> ② **右手板 A 的 3D 模型其实已经导出**（「model\pcb\右手板.step」（本地路径，非仓库交付文件））⇒ ⛔ 不是"缺料"。

---

## 〇、⭐ 硬日历（⛔ 不可谈判）

| ⭐ 日 | ⭐ 事件 | ⭐ 对排期的影响 |
|---|---|---|
| **10/1 四** | ⭐ 假期 D1（今晚） | 定方案 |
| **10/2 五** | D2 | 🔴 **冻结日**（见 §三） |
| **10/3 六** | D3 | 拓展板原理图 |
| **10/4 日** | D4 | 🔴 **嘉立创最后一个停产日** |
| ⭐⭐ **10/5 一** | ⭐⭐ **嘉立创【复工】**（生产 ＋ 发货恢复） | ⭐⭐ **下单窗口 —— 越早越好** |
| **10/6 二** | D6 | 控制板 / 模型装配核对 |
| ⭐ **10/7 三** | ⭐ **假期最后一天** | 🔴 **模型必须出 STL** |
| ⭐ **10/8 四** | ⭐ **回实验室** | ⭐ **3D 打印开打** |
| **10/9 五** | 工作日 | 打印迭代 · PCB 到货窗口 |
| **10/10 六** | ⭐ **调休上班** | 多一个工作日 |
| ⭐ **11/3** | ⭐ **比赛截止** | 倒排 |

⭐ **来源**：国庆假期 = [国务院办公厅 2026 年节假日安排（10/1–10/7 放假 · 10/10 上班）](https://www.shanghai.gov.cn/nw17239/20260930/e4dc5e3b91e84c19a743085439ac306e.html)；
嘉立创 PCB = [JLCPCB 2026 年 9–10 月假期安排（10/1–10/4 停产停发 · 10/5 全面恢复）](https://jlcpcb.com/news/jlcpcb-september-october-2026-holiday-schedule)。

⭐⭐ **本排期最重要的一条推论**：

```text
⭐ 10/5 嘉立创就复工了，而你还在假期里
⇒ ⭐ 谁能在 10/5 早上把 Gerber 交上去，谁就比"收假再下单"早【3 天】回板
⇒ ⭐ 所以 10/2~10/4 这三天是【决胜窗口】
```

---

## 一、线 A · PCB（嘉立创）

### A-1 ⭐ 现状（⭐ 与初版判断不同）

| ⭐ 板 | ⭐ 有没有原理图/PCB | ⭐ 卡在哪 |
|---|---|---|
| ⭐ **Console 拓展板** | 🔴 **没有**（全仓 glob `*.epro`/`*.sch`/`*.pcb`/`*.gbr` 零命中） | 🔴🔴 **"插哪些座"没跟着换板更新** —— 现行 P1 定义（`J13`/`J14`/`J8`/`J9`）**全是 `Tang Mega NEO Dock` 口径**；⭐ Console 上实际是 **`J9`/`J10`（各 2×20）＋ `PMOD0`/`PMOD1`** ⇒ ⭐ **全仓找不到 09-22 之后的重定义文档** ⇒ **原理图第一笔落不下去** |
| 🔴 **通用控制板** | 🔴 **没有** | 🔴 **"键数与接口"未定** —— 09-30 已把早先分的 10 根引脚（`N27`~`N39`）**全部撤回**、`OLED` 取消 ⇒ 旧座表/尺寸/上拉清单**全部作废** |

> ⚠️ **命名撞车（⭐ 写文档必须带限定词）**：⭐ **Dock 的 `J9`** = 2×20 扩展排针；
> ⭐ **拓展板（P1）自己的 `J9`** = **电源座（2×8，来自 P2 电源板）** ⇒ 两者同名不同物。
> 📌 同理：`files/10-硬件/正式板引脚与连接器.md`（09-14）说"`J9` = PMOD0（2×6）" ⇒ ⭐ **那是 NEO Dock 的编号**。

### A-2 ⭐ 拓展板要引什么（⭐ 信号级**已冻结**，⭐ 板级**未冻结**）

**信号级 —— ✅ 以 `constr/top.cst` 为准（⭐ 这条是硬的）**：全部挂在 **Dock 的 `J9`**（2×20 `EX CONN.`）的 `N1`~`N26`：

| ⭐ 组 | ⭐ 针 | ⭐ 信号（ball） |
|---|---|---|
| SPI 共享 | `N1` / `N2` | `spi_sclk`(`E14`) / `spi_mosi`(`E13`) |
| 片0 = **左手板 1** | `N3` / `N4` | `spi_miso[0]`(`C15`) / `spi_cs_n[0]`(`C14`) |
| 片1 = **左手板 2** | `N5` / `N6` | `spi_miso[1]`(`B13`) / `spi_cs_n[1]`(`C13`) |
| 片2 = **右手板 A** | `N7` / `N8` | `spi_miso[2]`(`A14`) / `spi_cs_n[2]`(`A13`) |
| 片3~5 = 备用 | `N9`~`N16` | 预留 |
| 电源 | `N11` / `N12` | `+5V` / `GND` |
| LED 共享 | `N17` / `N18` / `N19` | `led_le`(`A21`) / `led_sdi`(`B21`) / `led_clk`(`B18`) |
| LED `OE`×5 | `N20`~`N24` | `led_oe_n[0..4]`（`B17`/`C17`/`D17`/`A19`/`A18`，⭐ **低有效**） |
| UART | `N25` / `N26` | `uart_tx`(`D15`) / `uart_rx`(`D14`) |
| ⭐ 另挂 `PMOD1` | `IO3/4/5` | 外置 DAC I2S：`BCK`(`F20`) / `LRCK`(`E22`) / `DIN`(`D22`) |
| ⭐ 另挂 `PMOD1` | `IO6/IO7` | 拨弦比较器：`TRIG_UP`(`E21`) / `TRIG_DN`(`D21`) |

**插座侧**（对端板已写死的座，⭐ 以 `已画PCB网表核对.md` 为准）：

| ⭐ 外设 | ⭐ 座型号 | ⭐ 针定义 |
|---|---|---|
| 左手板 1 / 2 | `CONN-TH_8P-P2.50_HC-XH-8A-G` | `CS/GND/MOSI/GND/MISO/GND/MCP_CLK/GND` |
| 左手板 1 / 2 | 同上（`LED_1`） | `LE/GND/LED_CLK/GND/SDI/GND/OE/GND` |
| 左手板 1 / 2 | `CONN-TH_4P-P2.50` | `5V_A`/`AGND` · `5V`/`GND` |
| 右手板 A | `CONN-TH_8P-P2.50_ZX-XH2.54-8PWZ`（弯针） | 同 SPI |
| 右手板 A | `CONN-TH_4P-P2.50_ZX-XH2.54-4PWZ`（弯针） | `TRIG_UP/GND/TRIG_DN/GND` |
| 拓展板自己的 `J9`（电源） | **2×8 = 16pin / 2.54 mm** | 🔴 **电气参数未冻结**（电压轨/电流/针序/上电顺序/地分区） |
| 对插 Dock | 双排排针 **2×40P ×7** ＋ 双排母座 **2×20P ×10** | ⚠️ **已在采购清单里**（⭐ 但那是 NEO Dock 数量口径，⭐ 需按 Console 重核） |

> 🔴 **⛔ 别照 `files/10-硬件/拓展板连接方案.md` §三 算帧预算** —— 它把一笔 `MCP3208` 事务算成 **15 个 SCLK**，
> ⭐ 实际最少 **19**、驱动用 **24** ⇒ 连带 `2.69 kHz` 也是错的（⭐ `K-78` 已登记，⛔ 尚未改）。

### A-3 ⭐ 与 `第三周计划-v1.md` §3.4（W1~W4）的关系

| ⭐ v1 的硬件任务 | ⭐ 判据 | ⭐ v1 期限 | ⭐ 本排期的处理 |
|---|---|---|---|
| **W3** 拓展板原理图 ＋ PCB（引出 ADC/SPI/LED/串口屏/踏板/HDMI 座 ＋ 电源；预留按键与旋钮） | ⭐ **引脚清单与 `constr/top.cst` 对齐** | ⭐ 10/3 | ⭐ **细化**（⭐ 见下 A-4）：⭐ **先补"板级定义"再画** |
| **W1** 各部件 3D 建模：定位板、键帽、右手区、**踏板外壳**、整机装配 | ⭐ 可出图 / 可打印 | ⭐ 本周 | ⭐ **细化**（⭐ 见 §二）· ⚠️ **比用户点名的多"踏板外壳"＋"整机装配"** |
| **W2** 延音踏板选型、脚位确认、焊接 | ⭐ 可用；常开/常闭与极性已确认 | ⭐ 10/2 | ⚠️ **本次未排**（⭐ 用户点名的范围里没有）⇒ ⭐ **待确认要不要做** |
| **W4** 多按键控制板 ＋ 旋钮（数量与类型待定） | ⭐ 待定 | ⭐ TBD | ⭐ **= 本文的"通用控制板"** ⇒ ⭐ **A0 拍板项** |

### A-4 ⭐ 排期（线 A）

| ⭐ | ⭐ 任务 | ⭐ **能红判据** | ⭐ 目标日 |
|---|---|---|---|
| **A0a** | 🔴 **补"拓展板板级定义"**：⭐ 按 Console 重定**插哪些座**（`J9` ＋ `J10`？ ＋ `PMOD0`/`PMOD1`？）＋ 座表（`J1`~`J11` 哪些还要） | ⭐ 写出一张"插头↔插座"表，⭐ **每根针都能指到 `top.cst` 的行** | ⭐ **10/2** |
| **A0b** | 🔴 **拍板：通用控制板的键数与接口**（矩阵行列数 / 编码器 / 要不要显示） | 能写出"矩阵行列数"或"每键一根" | ⭐ **10/2** |
| **A0c** | 🔴 **冻结拓展板自己 `J9`（电源）的电气参数**（⭐ 跨人接口） | 电压轨/电流/针序/上电顺序/地分区**逐条有值** | ⭐ **10/2** |
| **A1** | ⭐ 拓展板**原理图** | ERC **0 错** ＋ ⭐ **逐针对 `top.cst` 核一遍**（⭐ = W3 判据） | ⭐ **10/3** |
| **A2** | ⭐ 拓展板 **PCB**（布局/布线/铺铜/丝印） | DRC **0 错** ＋ ⭐ 过 `画板注意事项.md` 的 **13 项自查清单** | ⭐ **10/4** |
| **A3** | ⭐ 控制板**引脚分配**（⭐ **FPGA 侧**：`constr/top.cst` ＋ `rtl/top.v` 端口） | ⭐ 走完**四道门** | 10/3~10/4 |
| **A4** | 控制板原理图 ＋ PCB | ERC/DRC 0 错 | 10/5~10/6 |
| **A5** | ⭐⭐ **下单** | 订单已提交 ＋ 工程确认（⭐ 板框 **≤100 mm** 免费额度） | ⭐ **拓展板 10/5 早** ／ 控制板 10/6~10/7 |
| **A6** | **回板验收** | 目视/通断/座子朝向/上电前检查 | ⭐ **预计 10/9~10/12** |

> ⚠️ **下单策略要你定**（见 §三-2）：① **两块拼一版合并下单**（省免费额度，⚠️ 控制板必须 10/5 前 ready）② **分两单**（拓展板先走，早 1~2 天回板）。
> ⚠️ **另两件卡开工的事**：⭐ **拓展板归谁画未定**（`板子划分与板间接口.md:27,:367`）· ⚠️ **器件备料 10 月才到货** ⇒ ⭐ 打样回来也可能**等料才能装**。

---

## 二、线 B · 模型（⭐ 建模在假期，⭐ 打印在 10/8 回实验室）

> ⭐ **设计总纲（⭐ 回答"要建成什么样"）** ⇒ `files/10-硬件/机械设计总纲-20261002.md`
> ✅ **轴间距 = 25 mm** —— 🔴🔴 **2026-10-03 用户澄清：实物本来就是 25 mm ⇒ ⛔ 不用重画板！**
> ⇒ ⭐ **本文 §B-2 / §B-3 / §四 R6 里的 20 mm 尺寸链口径（含"列间距 20 / 跨缝 20 / 留边各 10 /
> 8 列跨距 140 / 板宽 ~100"）是【文档错误】，全部作废** —— ⭐ **要改的是文档，⛔ 不是板子**。
> ⇒ ⭐ 真实尺寸（板宽 / 排间距 / 跨缝 / 留边）**以实测为准**（见本文 §二 `B-0`）。
> ⇒ ⭐ 画板专用对话的交接文档：`files/10-硬件/交接-画板专用对话-20261003.md`

### B-1 ⭐ 现有模型（⭐ 逐目录点过；⭐ 目录**不进版本库**，`.gitignore:96`）

| ⭐ 目录 | ⭐ 内容 | ⭐ 最新 | ⭐ 状态 |
|---|---|---|---|
| `model\pcb\` | 88 个（立创 EDA 导出） | 09-23 | ⭐⭐ **左手板 ＋ 右手板都在** —— `左手板.SLDASM`(09-21) · `左手板单板.SLDASM`(09-23) · ⭐ **`右手板.step`(09-19, 15.5 MB)** · `右手板单板.step` ⇒ 🔴 **初版说"右手板没导出"是错的** ✅<br>⚠️ **右手板只有 `.step`、缺 `.SLDASM`**（左手板两者都有） |
| `model\定位板\` | `定位板.SLDPRT` | 09-23 | ✅ **已建**（⭐ 与 `左手板单板.SLDASM` 同一时间戳 ⇒ 同一次会话） |
| `model\step\` | `定位板.STEP` · `键帽1.0.STEP` · `左手板单板.STEP/.SLDASM` | 09-23 | — |
| `model\` 根 | `键帽1.0.SLDPRT`(09-13) · `Keyboard Swidget.stl`(09-12) · `obj_1_Object_1.stl`(2025-11) | 09-13 | ⚠️ 键帽只有 **1.0** |
| 🔴 `model\键帽\` | **空目录** | — | 🔴 **一个文件都没有** |
| 🔴 外壳 / 面板 / 右手区结构件 | — | — | 🔴 **全 `model\` 下零命中** |

> ⚠️ **`机械与硬件待做任务表.md` 的状态列不可信**（⭐ 09-13 版、⛔ 未回填）：
> 它把 B1「16 孔定位板建模」记为 ⬜，⭐ **而 `定位板.SLDPRT` 09-23 就在磁盘上** ⇒ ⭐ **"文档说没做" ≠ 没做**。

### B-2 ⭐ 四类目标模型 × 设计输入

| ⭐ 类 | ⭐ 已有的输入 | 🔴 缺什么 | ⭐ 能否现在开做 |
|---|---|---|---|
| ⭐ **键帽**（圆角/刻音名/下缘开窗） | ⭐ 形式（3D 打印矮帽）· 圆角 · 开窗 **0.6~0.8 mm** · 侧裙壁厚 **0.6~0.8 mm** · 顶面微凹 · 刻深 **0.4~0.6 mm** / 字号 **5~6 mm** · 间隙 **1 mm** · 顶面朝上打印 · ⭐ **A2 冲突已裁定（八度级）⇒ 音名可刻死** ✅ | 🔴 **轴体型号待定**（`硬件选型表.md:1564`）＋ 🔴 **C3「量磁轴底座外廓」未实测** ⇒ ⭐ **键帽内孔/轴心接口没输入** | ⚠️ **先量轴体**（⭐ 见 B-0） |
| ⭐ **右手区结构件**（拨片/摇杆/推子固定） | ⭐ 摇杆 = `YF13-ZL7.4-B5Ka(45-10)-G` ＋ **实测 0.4~11.0 kΩ / 0.116~3.184 V** ✅ · 推子 **75 mm `B10K`×2 ⛔ 必须横放** · 板 A ≈ **100×92 mm** · `SCREW1~4` = M2 | 🔴 **拨片行程/角度/力臂未定**（`规划待办清单.md:106` **C16**）· ⚠️ 板 A 与左手板的拼接边长度对齐**待定** · ⚠️ 摇杆在板上的**位置/朝向**未给 | ⚠️ **先定 C16** |
| ⭐ **整机外壳 / 面板** | ⭐ 分体式 ✅ · 坐演为主、面板可轻微前倾 ✅ · 屏/旋钮位置不敏感 ✅ · 面板要承载（音频口/电源/开关/编码器板）✅ | 🔴 **整体尺寸无定案**（⭐ 形态决议自己写"尺寸暂不精确"）· 🔴 **倾角无数值** · 🔴 **面板开孔清单未定** · 🔴 **屏 6 寸 vs 7 寸未裁定** · 🔴 右手区机械尺寸未定 · 🔴 定位板高度未定 ⇒ 键帽顶面高度未定 | 🔴 **被决议卡住** |
| ⭐ **PCB 3D 装配核对** | ⭐ 左手板/右手板 3D ✅ · 定位板 ✅ · 现行尺寸链口径（列间距 **20** / 跨缝 **20** / 留边各 **10** / 8 列跨距 **140** / 板宽 **~100**） | 🔴 **板框未确认**（PDF **115×62** vs 文档 **60×40**）· 🔴 **"跨缝 20 mm"是 09-13 才改的，而两板已打样** ⇒ 实际用哪版**查不到** | ⚠️ **先量实物板** |

> ⭐⭐ **一个必须先做的零依赖活（B-0）**：**拿卡尺量磁轴底座外廓 ＋ 量两板实际板框/跨缝** ——
> ⭐ 它同时解锁 **键帽内孔**、**PCB 尺寸链**、**定位板高度** 三件事（⭐ `C3` / `对外问询清单 P4`）。
> ⭐ 另有实测警告：**装了定位板后磁轴行程只剩 1/3**（0.20 V / 248 码 vs 不装 0.60 V / 744 码）
> ⇒ ⭐ **已建那版定位板的高度很可能要改**（⭐ 建议按 `硬件选型表.md:1351` 的"垫块试高度"法）。

### B-3 ⭐ 排期（线 B）

| ⭐ | ⭐ 任务 | ⭐ **判据** | ⭐ 目标日 |
|---|---|---|---|
| **B0** | 🔴 **量实物**：磁轴底座外廓 ＋ 两板实际板框/跨缝 ＋ 定位板高度对照 | ⭐ 数字落纸 ＋ ⭐ **跨缝口径与实际板子一致** | ⭐ **10/2** |
| **B1** | ⭐ **键帽 v2**：上边缘大圆角 ＋ 顶面凹刻音名（0.4~0.6 mm）＋ 下缘开窗（0.6~0.8 mm） | ⭐ 打印后**手指划过不绊** · 刻深/壁厚在公差内 | ⭐ **10/4** |
| **B2** | ⭐ 右手区结构件：拨片 ＋ 摇杆/推子固定件（⭐ 需先定 `C16` 行程/角度） | ⭐ 与右手板 A 的孔位/座子**装配无干涉** | ⭐ **10/5** |
| **B3** | ⭐ **定位板高度重定**（⭐ 按实测：现版把行程压到 1/3） | ⭐ 装定位板后行程 ≈ 不装的量级（⭐ 对比 ADC 码） | 10/5 |
| **B4** | ⭐ PCB 3D 装配核对（左手板×2 ＋ 右手板 A ＋ 拓展板/控制板） | ⭐ **干涉检查 0 冲突** ＋ 排线走向不打架 | 10/6~10/7 |
| **B5** | ⭐ 整机外壳 / 面板（含开孔；⭐ 先裁**屏 6/7 寸**） | ⭐ 所有器件/座子/排线都能落位 | 10/7 |
| **B6** | 🔴 **出 STL ＋ 打印参数**（层高/摆放/孔径补偿） | ⭐ **10/8 一上班就能直接开打** | ⭐ **10/7 晚** |

> ⚠️ **打印相关约束**（⭐ 逐条有出处，⛔ 但**层高/喷嘴/填充率全仓查不到**）：
> FDM 孔径偏小 **0.1~0.3 mm** ⇒ 放大 **0.15~0.3 mm** 或铰刀修 · 键帽**顶面朝上 ＋ 低层高** ·
> 定位板孔轴**平行 Z 轴**防椭圆 · 两排共面 **±0.1 mm** · 材料 **PLA/PETG/ABS 待定** ·
> ⛔ **禁用铁质螺丝 / 钢定位板**（磁铁会吸）⇒ 铝 / 黄铜 / 尼龙 / PLA。
> ⚠️ `硬件选型表.md:469` 写"3D 打印机 **Bambu A1（自有）**" ⇒ ⭐ 与"收假回**实验室**打"的差异请你确认（⭐ 若是同一台就没事）。

---

## 三、⭐ 需要拍板（3 条；⭐ 已核：**不在** `待你拍板清单-20261001.md` 里）

| ⭐ # | ⭐ 事项 | ⭐ 选项 | ⭐ 最晚 |
|---|---|---|---|
| **1** | 🔴 **通用控制板的键数与接口** | ① 矩阵键盘（几行几列）② 每键一根 ③ 带编码器/显示？ | ⭐ **10/2**（⛔ 再晚赶不上 10/5 窗口） |
| **2** | ⭐ **下单策略** | ① 两块**拼一版合并下单**（省免费额度，⚠️ 控制板必须 10/5 前 ready）② **分两单**（拓展板先走，早 1~2 天回板） | ⭐ 10/4 |
| **3** | ⚠️ **拓展板插哪些座**（⭐ 换板后没人重定）＋ **`PMOD1` 那 5 根**要不要做进板子 | ① 只插 Dock `J9` ② `J9`＋`J10` ③ `J9`＋`PMOD1` ④ 全插 | ⭐ **10/2**（⭐ 卡 A1 第一笔） |

> ⭐ **另两条待确认（⭐ 不影响主排期）**：① `第三周计划-v1` 的 **W2 延音踏板**（选型/焊接，10/2）要不要做；
> ② **W1 还含"踏板外壳 ＋ 整机装配"** ⇒ 要不要并入本次模型范围。

---

## 四、⚠️ 风险

| ⭐ | ⭐ 风险 | ⭐ 后果 | ⭐ 缓解 |
|---|---|---|---|
| **R1** | 🔴 **拓展板"板级定义"10/2 没补出来** | ⭐ A1 第一笔落不下去 ⇒ ⭐ **撞 10/5 窗口** | ⭐ 10/2 只做**一张"插头↔插座"表**（⛔ 不画图），⭐ 照 `top.cst` 抄 |
| **R2** | 🔴 控制板键数 10/2 定不下来 | ⭐ A3~A5 顺延 | ⭐ **先按"最小可用"定**（如 `4×4` ＋ 1 编码器），⭐ 后续加键靠**预留行列** |
| **R3** | ⚠️ 10/5 早上 Gerber 没准备好 | ⭐ 掉到 10/8 下单 ⇒ **回板晚 3 天** | ⭐ 10/4 晚"**空跑导一次 Gerber**"（⭐ 拿左手板旧设计练流程） |
| **R4** | ⚠️ 模型 10/7 没出 STL | ⭐ 10/8 回实验室**没活干** | ⭐ 10/7 晚**只做导出**（⭐ 不再改设计） |
| **R5** | ⚠️ 板子改了引脚而 `top.cst`/`top.v` 没同步 | 🔴 **接上没反应**（⭐ 同 `K-141` 那类"文档↔代码不一致"） | ⭐ 引脚**只在一处定**（`constr/top.cst`）⇒ 画板照它抄，⭐ 画完**逐针回核** |
| **R6** | ⚠️ **尺寸链两套口径并存**（旧 15/105/60 vs 新 20/140/~100，⭐ `K-37`） | ⭐ 建模/画板用错口径 ⇒ **投板后改不了** | ⭐ 一律用**新口径**（`硬件接口总表.md:753`）＋ ⭐ **B0 量实物核实** |
| **R7** | 🔴 **`K-171`：实物档 `Fmax` 只剩 `+0.27%`** | ⭐ 控制板要加 RTL ⇒ ⚠️ **可能过不了时序** | ⭐ ⛔ **不是"重跑几次看运气"** —— ⭐ `第三周计划-v2` §六 实测：**本机对本设计是确定性的**（两次 attempt 的 Fmax **逐位相同**）⇒ ⭐ **必须真降逻辑或改关键路径** |

---

## 五、⭐ 与 FPGA 线 / 第三周计划的关系

| ⭐ | ⭐ 事 | ⭐ 说明 |
|---|---|---|
| ⭐ **谁做** | ⭐ **FPGA 线（`T3`/判据/门序）由我跑**；⭐ **PCB 与模型的动手活是你** | ⭐ 你只在"需要上板 / 需要实物尺寸"时介入 |
| ⭐ **耦合点 1** | ⭐ **控制板引脚分配 = 一次 `constr/top.cst` ＋ `rtl/top.v` 改动** ⇒ ⭐ 必须走**四道门** | ⭐ 键数一拍板我就能同步做 |
| ⭐ **耦合点 2** | ⭐ **键帽刻音名** 依赖"起始音只按八度级" ⇒ ✅ **FPGA 侧已按八度级实现**（`T2`/`BA`） | ⭐ 冲突已解，⭐ 可以放心刻 |
| 🔴 **耦合点 3** | 🔴 **`K-171`（实物档 `Fmax` 只剩 `+0.27%`）** | ⭐ 控制板 RTL 要不要加、怎么加，**取决于这条**；⭐ 且 FPGA 侧占用已 **80.1%** ⇒ ⚠️ **加不动** |
| ⭐ **排期冲突** | ⚠️ `第三周计划-v1` 排"拓展板原理图 10/1 · 布局 10/2 · 布线 10/3"；⭐ 本文排"10/3~10/4" | ⭐ 差 1~2 天的原因：⭐ v1 假设"引脚清单现成"，⭐ 而盘点发现**板级定义没更新** ⇒ ⭐ **A0a 是新增的前置** |

---

## 六、⭐ 一句话

```text
⭐ 10/2 三件事：① 补"拓展板插哪些座"的表 ② 拍控制板键数 ③ 量实物（轴体底座＋板框＋跨缝）
⭐ 10/3~10/4 拓展板 原理图 → PCB（⭐ 过 13 项画板清单）· ⭐ 10/5 一早就下单
⭐ 模型：10/2 量实物 → 10/4 键帽 v2 → 10/5 右手区＋定位板高度 → 10/6~10/7 装配核对＋外壳 → ⭐ 10/7 晚出 STL
⭐ 10/8 回实验室：开打；⭐ 10/9~10/12 PCB 回板
```
