hokuu1102/Gowin2026-PolySynth/files/10-硬件/交接-画板专用对话-20261003.md

# 🔧 画板专用对话 · 交接文档（2026-10-03）

> **用途**：⭐ **新开一个专门梳理硬件/画板的对话时，把这份文档交给它**。
> ⭐ **它回答三件事**：① **家底是什么** ② **现在按哪套口径画** ③ **还没定的是什么**。
> ⛔ **本文是索引与口径**，⭐ **细节一律以它引用的原文档为准**（本文会过时，原文档不会）。
>
> ⚠️ **本文写作时间 = 2026-10-03 凌晨**。⭐ **日期敏感的内容（排期/倒计时）请以实际日期重算**。

---

## 〇、⭐⭐ 先看这 5 条（最重要的口径）

| # | 口径 | 出处 |
|---|---|---|
| **1** | 🔴 **轴间距 = 25 mm —— ⭐ 而且【硬件本来就是 25 mm】**（2026-10-03 用户澄清）⇒ ⛔ **不用重画板**；🔴 **是【文档】写错了**（多份文档写 20 mm / 8 列跨距 140 mm）⇒ ⭐ **要把文档改对，⛔ 不是把板子重画** | `机械设计总纲-20261002.md` §〇-A 裁定 1（⭐ 已按 2026-10-03 澄清更正） |
| **2** | 🔴 **引脚只有一处真相源 = `constr/top.cst`** ⇒ 画板**照它抄**，⭐ **画完逐针回核**（⛔ 不许在别处另定引脚） | `files/00-总览/国庆安排-PCB与模型-20261001.md` §四 R5 |
| **3** | 🔴 **嘉立创 10/1–10/4 停产停发、10/5 复工** ⇒ ⭐ **下单窗口 = 10/5 早上**（越早越好，早 3 天回板） | 同上 §〇（含官方链接） |
| **4** | 🔴 **本机对本设计是确定性的**（同源两次 PnR 的 Fmax 逐位相同）⇒ ⭐ **不许"重跑几次看运气"**，必须真改逻辑 | `files/00-总览/第三周/第三周计划-v2-实测修正版.md` §六 |
| **5** | ⚠️ **`拓展板连接方案.md` §三 的 SPI 帧预算算错了**（把一笔 MCP3208 事务算成 15 SCLK，实际最少 19、驱动用 24）⇒ ⛔ 别照它算 | `K-78`（`files/20-代码/已知问题与风险清单.md`） |

---

## 一、家底：板子现在到哪一步了

| 板 | 状态 | 口径/尺寸 | 备注 |
|---|---|---|---|
| **左手板 1 / 2** | ✅ **已打样 + 已焊接** | ✅ **25 mm 轴间距**（⭐ **实物本来就是 25 mm**；⚠️ **文档里的 20 mm 是错的**） | 每板 1 片 `MCP3208` + 1 片 `TLC5916`；座 = `CONN-TH_8P-P2.50_HC-XH-8A-G` ×2 + `CONN-TH_4P-P2.50` |
| **右手板 A** | ✅ **已打样 + 已焊接** | 板 A ≈ **100 × 92 mm** | 座 = `CONN-TH_8P-P2.50_ZX-XH2.54-8PWZ`（弯针）+ `CONN-TH_4P`（TRIG_UP/GND/TRIG_DN/GND） |
| **电源板（P2）** | ✅ **已画完**（原理图在库） | — | `files/10-硬件/原理图/电源板.zip` |
| **Console 拓展板** | 🔴 **没画**（全仓 `*.epro/*.sch/*.pcb/*.gbr` 零命中） | — | 🔴 **卡在"插哪些座"没跟着换板更新**（见 §四-A0a） |
| **通用控制板** | 🔴 **没画** | — | 🔴 **卡在"键数与接口"未定**（见 §四-A0b） |
| **板 B** | 🔴 **原理图尚未画** | — | ⭐ `K-33`：`K-14`（OLED SPI mode）/`K-15`（双色灯映射）/`K-26`（显示口径）全挂在它上面 |

**3D 模型家底**（⭐ 「model/」（本地路径，非仓库交付文件） **整个目录不入库**，`.gitignore:96`；⚠️ 「model/pcb/左手板.step」（本地路径，非仓库交付文件） 是**早期误入库**、已在历史里）：

| 目录 | 内容 | 状态 |
|---|---|---|
| `model\pcb\` | 88 个（立创 EDA 导出） | ⭐ **左手板（`.SLDASM`）+ 右手板（`.step`）都在**；⚠️ 右手板**缺 `.SLDASM`** |
| `model\定位板\` | `定位板.SLDPRT` | ✅ 已建（09-23） |
| `model\step\` | 定位板/键帽 1.0/左手板单板 的 STEP | — |
| 🔴 `model\键帽\` | **空目录** | 🔴 一个文件都没有 |
| 🔴 外壳/面板/右手区结构件 | — | 🔴 **全 `model\` 下零命中** |

---

## 二、⭐ 2026-10-02 的两条裁定 + 连带重算清单

> 出处：`files/10-硬件/机械设计总纲-20261002.md` §〇-A（⭐ **它是"要建成什么样"的意图记录**）

### 裁定 1 · ✅ **轴间距 = 25 mm（⭐ 实物本来就是 25 mm，⛔ 不用重画）**

> ⚠️ **2026-10-03 用户澄清**：⭐ **"不用重新画，本来就是 25 mm 的轴距"**
> ⇒ 🔴 **原裁定里"要重画板 / 已打样的旧板被取代"的推论【作废】** —— ⭐ **错的是【文档】，⛔ 不是板子**。

| 项 | 内容 |
|---|---|
| ⭐ **实物** | ✅ **左手板两块本来就是 25 mm 轴间距**（已打样焊接的那两块，⛔ 不用动、不用重画） |
| 🔴 **要改的是文档** | 多份现行文档写 **20 mm**（含"列间距 20 / 跨缝 20 / 留边各 10 / 8 列跨距 140 / 板宽 ~100"）⇒ ⭐ **这些都是错的**，要按 25 mm 改 |
| 数值（按 25 mm 推） | 8 列轴心跨距 = **7 × 25 = 175 mm**（⛔ 不是 140）；单块（4 列）= **3 × 25 = 75 mm**<br>⚠️ **板宽/留边/跨缝的【真实值】必须以实物测量为准**（⭐ 见 §四-C 的 B0） |
| ⚠️ 排间距 | 原稿写 **25 × 25 网格** ⇒ 排间距 **可能也是 25 mm**；⚠️ 而文档里写 **12～15 mm** ⇒ 🔴 **需实测确认** |
| 🔴 连带要改的文档 | `硬件接口总表.md:139-150`（20 mm 段）· `机械与硬件待做任务表.md:78`（写"列间距 15 mm"）· `左手区方案.md:219`（排间距 12~15）· ⭐ **双模式映射表**（"每半音多少 mm"依赖列间距）· 定位板 16 孔坐标（⭐ 必须与实物一致） |
| ✅ 不变 | 仍是 **2 行 × 8 列 = 16 轴位** ⇒ ⭐ ADC 通道（每板 1 片 `MCP3208`）**不用改** |
| ⚠️ 待你答 | ⭐ **实物的 板宽 / 排间距 / 两板跨缝 / 留边 各是多少？**（⭐ 量出来才能把文档改对，也才能画拓展板/控制板） |

### 裁定 2 · ⭐ **键帽透光走"侧刻"**

- 键帽主体**不透明**（黑/白 PLA）＋ **侧刻** ＋ 蓝光经**导光柱**送到侧壁
- ⭐ **与已实测方案并存**：**下缘开窗 0.6~0.8 mm**（已实测"比较清楚"）管"哪个键在亮"；侧刻管"这个键是什么"
- 🔴 **两个未验证前提**：① **轴体是否带中心导光柱**（项目里仍是待核实项；若只有**下灯位** ⇒ 侧壁能不能亮**必须打样验证**）② **侧刻是凹刻还是贯穿**（⚠️ **凹刻不发光**，贯穿才发光）

---

## 三、文件地图（哪份文档管什么）

| 文档 | 管什么 | 状态 |
|---|---|---|
| `机械设计总纲-20261002.md` | ⭐ **"要建成什么样"**（整体机械架构/键帽/外壳/侧刻）+ §〇-A 两条裁定 | ✅ **最新，优先读** |
| `硬件接口总表.md` | 硬件接口总表（43 KB） | ⚠️ 含 20 mm 旧口径 ⇒ 以裁定为准 |
| `Console引脚与控制接口总表-20261001.md` | ⭐ **Console 的引脚/控件/排针三合一** | ✅ 现行 |
| `拓展板连接方案.md` | 拓展板连接拓扑 / SPI 引脚 / 上拉 / 防错插 / 上电顺序 / **§六 待确认项** | ⚠️ **§三 帧预算错（K-78）** |
| `左手区方案.md` / `右手板方案.md` | 左手区/右手板方案 | ⚠️ 含旧尺寸链 |
| `画板注意事项.md` | ⭐⭐ **地 / 电源轨 / 分区布局 / 走线 / 电平兼容 + 【13 项画完自查清单】** | ✅ **画板必读** |
| `左手板原理图评审.md` | 左手板原理图评审结论 | ✅ |
| `已画PCB网表核对.md` | ⭐ **对端板已写死的座型号与针定义** | ✅ 画板对插必查 |
| `板子划分与板间接口.md` | 板子划分与板间接口 | ✅（⭐ `:27/:367` 有"拓展板归谁画未定"） |
| `机械与硬件待做任务表.md` | 键帽 A1~A11 · 定位板 B1~B5 · **轴体/手感实测 C1~C6** | 🔴 **状态列不可信**（09-13 版未回填）· ⚠️ B1 写"列间距 15 mm" = **旧口径** |
| `采购与验证清单.md` / `排线采购-最终形态-20260923.md` | 采购 | ⚠️ 部分是 NEO Dock 数量口径 ⇒ 需按 Console 重核 |
| `原理图\*.pdf|.tel` | 左手板/右手板 A 原理图 | ✅ |
| `板卡替换评估\*` | 换板评估（Console 替换 NEO Dock） | ✅ 背景 |
| `model\`（**不入库**） | 3D 模型 | ⭐ 家底见 §一 |

---

## 四、⭐ 还没定的事（新对话最该先问这些）

### A. 卡住"第一笔画不下去"的三件（⭐ 原计划 10/2 拍板，现已过期）

| # | 事项 | 选项 | 不定会卡住什么 |
|---|---|---|---|
| **A0a** | 🔴 **拓展板"板级定义"**：按 Console 重定**插哪些座**（`J9`＋`J10`？`PMOD0`/`PMOD1`？）＋ 座表（`J1`~`J11` 哪些还要） | ① 只插 Dock `J9` ② `J9`＋`J10` ③ `J9`＋`PMOD1` ④ 全插 | ⭐ **A1 原理图第一笔**（信号级已冻结，**板级没冻结**） |
| **A0b** | 🔴 **通用控制板的键数与接口**（矩阵行列数 / 编码器 / 要不要显示） | ① 矩阵键盘（几行几列）② 每键一根 ③ 带编码器/显示？ | ⭐ 控制板原理图与引脚分配（`top.cst` 改动） |
| **A0c** | 🔴 **拓展板自己的 `J9`（电源座）电气参数**（电压轨/电流/针序/上电顺序/地分区） | — | ⭐ **跨人接口**，不定则电源部分画不了 |

> ⚠️ **命名撞车警告**：⭐ **Dock 的 `J9`**（2×20 扩展排针）⛔ **不是** ⭐ **拓展板自己的 `J9`**（电源座 2×8）⇒ 写文档必须带限定词。

### B. 其他开放问题（⭐ 从文档里抓的，逐条有出处）

| 事项 | 出处 |
|---|---|
| ⚠️ **排间距是否跟到 25 mm** | `机械设计总纲-20261002.md` §〇-A 裁定 1 |
| ⚠️ **旧板（20 mm）留作样机还是彻底取代** | 同上 |
| ⚠️ **侧刻是凹刻（不发光）还是贯穿（发光）** | 同上 裁定 2 |
| ⚠️ **轴体是否带中心导光柱** | `左手区方案.md:236` |
| ⚠️ **板框 ≤100 mm 免费额度是否还成立**（25 mm 后板宽 ≈100 mm） | `国庆安排…md` A5 |
| ⚠️ **拓展板归谁画** | `板子划分与板间接口.md:27,:367` |
| ⚠️ **下单策略**：两块拼一版合并下单 vs 分两单 | `国庆安排…md` §三-2 |
| ⚠️ **轴体型号待定 + `C3`（量磁轴底座外廓）未实测** | `硬件选型表.md:1564` · `机械与硬件待做任务表.md:90` |
| ⚠️ **`C16` 拨片行程/角度/力臂未定** | `规划待办清单.md:106` |
| ⚠️ **整机尺寸/倾角/面板开孔/屏 6 寸 vs 7 寸** | `国庆安排…md` §B-2 |
| ⚠️ **3D 打印材料（PLA/PETG/ABS）与层高/喷嘴/填充率** | `国庆安排…md` §B-3 注 |
| ⚠️ **`W2` 延音踏板（选型/焊接）要不要做** | `第三周计划-v1.md` §3.4 |

### C. 🔴 两个"实测才能解锁"的零依赖活（⭐ 最高优先）

| # | 活 | 为什么 |
|---|---|---|
| **C3** | ⭐ **拿卡尺量磁轴底座外廓** | 同时解锁 **键帽内孔** + **列间距能否压到目标值** + **PCB 尺寸链** |
| **B0** | ⭐ **量两板实际板框/跨缝 + 定位板高度对照** | ⚠️ **实测警告：装了定位板后磁轴行程只剩 1/3**（0.20 V / 248 码 vs 不装 0.60 V / 744 码）⇒ ⭐ **已建那版定位板的高度很可能要改** |

---

## 五、硬约束 / 已知坑（⭐ 画板前必须过一遍）

### 5.1 电气与布局（`画板注意事项.md`）

| # | 约束 |
|---|---|
| 1 | ⭐ **三条铁律**：共地但**分区** · 只送 **`+5V_A`**（⛔ 不送 `3V3_A`，**每板在使用点 LDO 生成**）· 模拟区与 LED/DC-DC **分居两端** |
| 2 | ⭐ **`GND` 与 `GND_A` 只在 P2 单点汇合**，别处不再连 |
| 3 | ⭐ **SPI 走线远离霍尔模拟走线**，中间加**地隔离带**；⛔ **模拟走线不要走在数字信号正下方/正上方** |
| 4 | ⭐ **LED 驱动用 `TLC5916`（8 路恒流，VDD=3.3 V）**，⛔ 不用 `74HC595`（5 V 供电器件的**输入门限**问题 + 每片总电流 ~70 mA 上限） |
| 5 | ⭐ **回给 FPGA 的信号摆幅 ≤ 3.3 V**；**板间排线"信号-地-信号-地"交错**；**每个电源脚 0.1 µF** |
| 6 | ⭐⭐ **画完对着 13 项自查清单勾**（`画板注意事项.md:340-352`） |

### 5.2 已登记的项目坑（`files/20-代码/已知问题与风险清单.md`）

| 编号 | 一句话 | 状态 |
|---|---|---|
| **K-06** | ⚠️ **每片 ADC 的 `MISO` 必须独立**（⛔ 不能硬并到一个 FPGA 输入） | ⬜ 待办 |
| **K-12** | ⭐ **不用 `74HC165`** —— 每板按键**直连 FPGA**（165 的 `QH` 没有三态） | ✅ 已定 |
| **K-13** | ⭐ **灯的移位 `CLK` 与 ADC 的 `SCK` 各自独立**，⛔ 不要复用 | ✅ 已明确 |
| **K-32** | ⭐ **`TLC5916` 分组**：各片 `SDI` **独立**；`LED_CLK`/`LE`/`OE` **可共用** | ✅ 已确认 |
| **K-33** | ⚠️ **板 B 原理图未画** ⇒ OLED/按键/双色灯端口无法冻结 | ⬜ 待办 |
| **K-37** | ⚠️ **左手区尺寸链旧值（15/105/~60）散落多份现行文档** ⇒ 🔴 **再叠加 25 mm 新裁定** ⇒ ⭐ 建议**统一到一处** | ⚠️ 未收口 |
| **K-78** | 🔴 **`拓展板连接方案.md` §三 帧预算错**（15 vs 19/24 SCLK） | ⚠️ 未改 |
| **K-141** | ✅ `.cst` 实际是 **UTF-8 无 BOM + LF**（原判 GBK 有误）；⚠️ **`.cst` 无编码守卫**仍成立 | ✅ 已更正 |
| **K-170/171** | ✅ 器件档位已修（原 `pn=` 不决定器件）；⚠️ 实物档 Fmax 余量曾只剩 **+0.27%**（⭐ 已被后续时序修复改善到 **53.425 MHz / +6.85%**） | ✅/⚠️ |

---

## 六、排期（⭐ 线 A = PCB，线 B = 模型；出处 `files/00-总览/国庆安排-PCB与模型-20261001.md`）

### 线 A · PCB

| 编号 | 任务 | 判据 | 原目标日 |
|---|---|---|---|
| **A0a/b/c** | 补"拓展板板级定义" / 拍控制板键数 / 冻结电源座参数 | 每根针能指到 `top.cst` 的行 | **10/2**（⭐ 已过期） |
| **A1** | 拓展板**原理图** | ERC **0 错** + ⭐ **逐针对 `top.cst` 核一遍** | 10/3 |
| **A2** | 拓展板 **PCB** | DRC **0 错** + ⭐ 过 **13 项自查清单** | 10/4 |
| **A3** | 控制板**引脚分配**（FPGA 侧：`top.cst` + `top.v`） | ⭐ 走完**四道门** | 10/3~10/4 |
| **A4** | 控制板原理图 + PCB | ERC/DRC 0 错 | 10/5~10/6 |
| **A5** | ⭐⭐ **下单** | 订单提交 + 工程确认（板框 ≤100 mm） | ⭐ **拓展板 10/5 早** |
| **A6** | 回板验收 | 目视/通断/座子朝向/上电前检查 | 10/9~10/12 |

### 线 B · 模型

| 编号 | 任务 | 判据 | 原目标日 |
|---|---|---|---|
| **B0** | 🔴 量实物（轴体底座 + 两板板框/跨缝 + 定位板高度） | 数字落纸 + 与实物一致 | 10/2 |
| **B1** | 键帽 v2（大圆角 + 顶面凹刻音名 + 下缘开窗） | 划过不绊 + 刻深/壁厚在公差内 | 10/4 |
| **B2** | 右手区结构件（拨片 + 摇杆/推子固定） | 与右手板 A **装配无干涉** | 10/5 |
| **B3** | 🔴 **定位板高度重定**（现版把行程压到 1/3） | 装定位板后行程 ≈ 不装的量级 | 10/5 |
| **B4** | PCB 3D 装配核对 | **干涉 0 冲突** + 排线不打架 | 10/6~10/7 |
| **B5** | 整机外壳/面板（含开孔；先裁屏 6/7 寸） | 所有器件/座子/排线都能落位 | 10/7 |
| **B6** | 🔴 出 **STL** + 打印参数 | 10/8 一上班就能直接开打 | **10/7 晚** |

> ⚠️ **25 mm 澄清之后**：⭐ **板子不用重画** ✅，但 🔴 **文档里的 20 mm 尺寸链是错的** ⇒
> ⭐ **A0a（板级定义）+ B0/C3（量实物拿真实尺寸）必须先做**，⛔ 否则画拓展板/控制板时会照错口径画。
> ⚠️ **打印约束**：FDM 孔径偏小 0.1~0.3 mm ⇒ 放大 0.15~0.3 mm · 键帽**顶面朝上** · 定位板孔轴**平行 Z 轴** · 两排共面 ±0.1 mm · ⛔ **禁铁质螺丝/钢定位板**（磁铁会吸）。

---

## 七、与 FPGA 线的耦合点（⛔ 别越界）

| 耦合点 | 规则 |
|---|---|
| **引脚** | ⭐ **只有一处真相源 = `constr/top.cst`**；⭐ 画板照抄 + **画完逐针回核**；⛔ 画板侧**不要自己另定引脚** |
| **改 FPGA 侧**（`top.cst`/`top.v`） | ⭐ **必须走四道门**（综合门 → 聚焦 tb → PnR → 全量回归）⇒ ⭐ **交给 FPGA 线做，⛔ 画板对话不要直接改 RTL/约束** |
| **键帽刻音名** | ✅ 依赖已解：⭐ **起始音只按八度级**（FPGA 侧已实现）⇒ **可以放心刻** |
| **控制板要加 RTL** | ⚠️ 取决于时序余量（当前含 H5 树 **53.425 MHz / +6.85%**，过 51.5 门槛）· ⚠️ 逻辑占用曾到 **80%+** ⇒ **加之前先问 FPGA 线** |
| **串口屏 / ESP32** | ⭐ 串口走 **`J9` 排针**（`TX→N26`/`RX→N25`，500000 8N1）；⛔ **板载 USB-C 走不通** |

---

## 八、⭐ 建议的开工顺序

```text
第 1 步（零依赖、当天可做）：⭐ 量实物 —— 轴体底座外廓（C3）+ 两板板框/跨缝 + 定位板高度对照（B0）
第 2 步（拍板）：⭐ A0a 拓展板插哪些座 · A0b 控制板键数 · A0c 电源座电气参数 · 排间距/旧板去留
第 3 步（画）：⭐ 拓展板 原理图 → PCB（过 13 项自查）⇒ ⭐ 赶 10/5 早下单窗口
第 4 步（模型）：键帽 v2 → 右手区 → 定位板高度 → 装配核对 → 外壳 → ⭐ 出 STL
```

---

## 附：本文档的边界

- ⛔ **本文不是设计输入**：⭐ **尺寸/电气参数一律以 §三 的原文档为准**，本文只做索引与口径汇总
- ⚠️ **本文写作于 2026-10-03 凌晨** ⇒ ⭐ 排期与倒计时请按实际日期重算
- ⭐ **发现本文与原文档冲突 ⇒ 以原文档为准**，并顺手更正本文

---

## 九、附录：参数双口径对照 + `top.cst` 的坑 + 补充问题

> 来源：一次**只读汇编**（2026-10-03，逐条带 `文件:行`）。⭐ **凡是标 `[20]` 的都是【文档写错】的口径，实物是 `[25]`。**

### 9.1 尺寸/参数双口径对照（⭐ 画板前必看）

| 参数 | ⭐ 正确值 `[25]` | 🔴 文档里写的 `[20]`（要改） | 出处 |
|---|---|---|---|
| 轴间距/列间距 | **25 mm** | 20 mm（09-13 由 15 改） | `机械设计总纲:34,:36` ↔ `硬件接口总表:145`·`左手区方案:63` |
| 8 列轴心跨距 | **175 mm** | 140 mm | `机械设计总纲:36` ↔ `硬件接口总表:150` |
| 单块 4 列跨距 | **75 mm** | — | `机械设计总纲:36` |
| 板宽/块 | ⚠️ **以实测为准** | ~100 mm（4×20+两侧 10） | `机械设计总纲:36` ↔ `硬件接口总表:149` |
| 留边 | ⚠️ **以实测为准** | 各 10 mm | `机械设计总纲:36` ↔ `硬件接口总表:147` |
| 跨缝 | **必须 = 列间距** | 20 mm（10+10） | `机械设计总纲:107`·`左手区方案:190` ↔ `硬件接口总表:146` |
| **排间距** | 🔴 **待确认**（原稿写 `25×25`） | 12~15 mm | `机械设计总纲:37` ↔ `左手区方案:64,:219`·`机械与硬件待做任务表:78` |
| 轴位数 | **2 行 × 8 列 = 16**（单板 2×4） | 两套相同 ✅ | `左手区方案:61-62`·`机械设计总纲:39` |

**其他已定参数**：键帽间隙 ~1 mm（25 mm 下键帽外廓可到 **~24 mm**）· 侧裙壁厚 0.6~0.8 mm · 刻深 0.4~0.6 mm / 字号 5~6 mm · 三明治 = **四层**（键帽/定位板/PCB/下壳）· 外壳倾向**白大理石 PLA**（正式材料待定）· 磁吸 ⚠️**已降为"可选/兜底"**（与总纲冲突，待裁）

### 9.2 左手板已写死的器件（⭐ 画拓展板/控制板时要对得上）

| 位号 | 器件/作用 | 备注 |
|---|---|---|
| `U1` | `MCP3208`（SOIC-16） | 每板 1 片 ADC |
| `U4` | `TLC5916`（SOIC-16） | 每板 1 片 LED 恒流驱动 |
| `U2` | LDO（`5V_A` → `3V3`） | ⭐ **使用点生成**（铁律） |
| `R13~R16` | 33 Ω 源端串阻 | — |
| `R10` | **0 Ω（`AGND` ↔ `GND` 唯一汇合点）** | ⭐ **必须放在 `U1` 正下方** |
| `R11` | `OE` 10 kΩ 上拉 | ⭐ **必焊** |
| `R12` | `LE` 10 kΩ 上拉 | ⭐ **建议不焊** |

### 9.3 ⭐ `constr/top.cst` 的坑（引脚唯一真值源，但它自己也有坑）

| # | 坑 | 规则 |
|---|---|---|
| 1 | 🔴 **`top.cst` 自己有 3 处过时注释**：`:53-55`（说 PMOD1_IO0/1/2 被 SPI 占用 —— 实际空）· `:139`（说 E21/D21 未分配 —— 实际已给拨弦）· `:150-151`（说 6 根是 D2..D7 —— 实际 sclk/mosi 在 D0/D1） | ⭐ **唯一真值 = `IO_LOC` 行，⛔ 注释不可信** |
| 2 | 🔴 **连接器编号一律以 Console 为准**：`J9`/`J10`（2×20）+ `PMOD0=J6`/`PMOD1=J7`；旧文档的 `J13/J14/J8/J9` 是 **NEO Dock** 的 | ⭐ 画板别用旧编号 |
| 3 | ⚠️ **`Y12` 身份有三套口径** | ⭐ 画板**只用 ball 号**，⛔ 不写 `Key_in[n]` |
| 4 | ⭐ **Console 5 条硬约束** | ① `AA13`/`AB13`/`Y14` 必须 **LVCMOS15 + BANK_VCCIO=1.5** ② 用 `J9`/`J10` 就**不能插 SDRAM 模块** ③ **所有输入脚写 `PULL_MODE=UP`**（板上无外部上拉），但 ⛔ **不给输入脚写 `DRIVE`**（`ERROR CT1108`）④ 🔴 **`J5` 是 BTL 喇叭输出 ⇒ 绝不能当 IO / 接有源音箱** ⑤ **JTAG 四根 + BANK9 16 根 + FPC-10P 一律别碰** |
| 5 | ⭐ **流程** | 引脚只在一处定（`top.cst`）⇒ 画板照抄 ⇒ **画完逐针回核**（= `W3` 判据） |

**画板照抄的 `top.cst` 实际行**：`spi_sclk=E14(N1)` · `spi_mosi=E13(N2)` · `miso[0]=C15(N3)`/`cs_n[0]=C14(N4)` · `miso[1]=B13(N5)`/`cs_n[1]=C13(N6)` · `miso[2]=A14(N7)`/`cs_n[2]=A13(N8)` · `miso[3..5]=B16/A16/A20`、`cs_n[3..5]=B15/A15/B20` · `led_le=A21(N17)`/`led_sdi=B21(N18)`/`led_clk=B18(N19)` · `led_oe_n[0..4]=B17/C17/D17/A19/A18(N20~N24·**低有效**)` · `uart_rx=D14(N26)`/`uart_tx=D15(N25)` · `PA_EN_n=Y14`（⚠️LVCMOS15）

### 9.4 补充的开放问题（⭐ 加上 §四 的一起问）

| # | 事项 | 不定会卡住 |
|---|---|---|
| 1 | ⚠️ **串口屏串口电平**（5 V TTL 还是 3.3 V）—— `J2` 只有 4 针，**加不了转换电路** | ⭐ **画 P1 前必定** |
| 2 | ⚠️ **`PA_EN` 在 Console 上已是别的功能**（经 `R54` 0R 接 `MAX98357A` 的 `SD_MODE`） | 音频使能脚最终接法 |
| 3 | ⚠️ **`K-32` 未冻结**：`RTL代码结构与接口规划.md` 已单方面写死"三组独立 LED 时钟/锁存"（9 根） | ⭐ **共用可省 6 根** ⇒ 冻结须二选一 |
| 4 | ⚠️ **`RIGHT_ADC_ENABLE` 默认值** | 板 A 没接好时颤音会拉满 |
| 5 | ⚠️ **摇杆在板上的位置/朝向** | `P4` 布局 |
| 6 | ⚠️ **板 A 与左手板的拼接边长度是否对齐** | 右手区最终机械尺寸 |
| 7 | ⚠️ **磁吸是"可选/兜底"还是按原稿提回采购单 + 做定位凸台/槽** | 外壳结构 |
| 8 | ⚠️ **`E7` 左手板飞线补 MISO 上拉 / `E8` 补 CS 上拉** 要不要做 | 上板可靠性 |
| 9 | ⚠️ **`W2` 延音踏板（选型/焊接）要不要做** | 踏板接口 |
| 10 | ⚠️ **3D 打印材料 + 层高/喷嘴/填充率**（全仓查不到） | `B6` 打印参数 |

### 9.5 外部依赖与倒计时（⭐ 每天开工前看一眼）

| 依赖 | 状态 | 影响 |
|---|---|---|
| 🔴 **嘉立创打样** | 10/1–10/4 **停产停发**，**10/5 复工** | ⭐ **下单窗口 = 10/5 早**；错过 ⇒ 回板晚 3 天 |
| 🔴 **3D 打印** | **10/8 回实验室**才能打 | ⭐ `B6` 必须在 **10/7 晚**出 STL |
| ⚠️ **器件备料** | 10 月才到货 | ⭐ 打样回来也可能**等料才能装** |
| ⚠️ **打印参数** | 层高/喷嘴/填充率**全仓查不到** | 要现场定 |
| ⭐ **比赛截止** | **11/3** | 倒排 |

> ⚠️ **另两件卡开工的事**：⭐ **拓展板归谁画未定**（`板子划分与板间接口.md:27,:367`）· 🔴 **A0a/A0b/A0c 三件拍板项已过期**（原定 10/2）⇒ **现在就得补**。
