hokuu1102/Gowin2026-PolySynth/files/10-硬件/机械设计总纲-20261002.md

# 🔧 机械设计总纲 —— 白色大理石外壳 · 模块化左手 · 钢琴式键帽

> **记录时间**：2026-10-02（凌晨）
> **来源**：⭐ **用户口述／整理的设计总纲**（与外部 AI 对话的整理稿）
> **性质**：⭐ **意图记录** —— 它回答「**要建成什么样**」，⛔ **不替代实物测量**
> **适用**：`model\` 下的 3D 建模（键帽 / 定位板 / 右手区结构件 / 整机外壳）＋ 后续 PCB 改版
> **配套**：⭐ 排期与判据见 `files/00-总览/国庆安排-PCB与模型-20261001.md` §二（线 B）
>
> ✅ **2026-10-02 已裁定（⭐ 见 §〇-A）**：**轴间距 = 25 mm（新方案，要重画板）** · **键帽透光走侧刻**
> ⇒ ⭐ 原稿这两个数**不是笔误**；⭐ 项目现行的 **20 mm** 与「下缘开窗」口径**被取代 / 并列**。

---

## 〇、⭐ 一句话设计原则（原稿照录）

> **以 25 mm 轴网格为核心基准，以 PCB 外边界定义模块边界，以磁吸实现模块自由组合，
> 以三明治结构实现 PCB/外壳固定；普通音符采用圆润键帽，多轴音符采用大键，
> 钢琴模式采用钢琴式键帽，鼓点采用大面积鼓垫；所有键帽统一考虑蓝色导光柱与侧刻发光，
> 外观采用白色大理石 + 黑白键 + 蓝光 + 少量橙色图标。**

⭐ **再压缩成四个词**：`白大理石壳` ＋ `模块化左手` ＋ `钢琴式键帽` ＋ `统一蓝光`

---

## 〇-A、✅ 2026-10-02 裁定（⭐ 两条 —— ⭐ 它们覆盖原稿与项目旧口径）

> ⭐ **裁定人：用户**（本会话，2026-10-02 凌晨）。
> ⭐ 下面每条 = **裁定内容** ＋ **由它推出的"必须重算"清单**（⭐ 后者才是真正要干的活）。

### 裁定 1 · ✅ **轴间距 = 25 mm**（⚠️ 标题里"要重画板"已作废，见下方更正）

> 🔴🔴 **2026-10-03 用户澄清 —— 它【覆盖本条裁定的"后果"部分】：**
> ⭐ **"不用重新画，本来就是 25 mm 的轴距"** ⇒ ⭐ **已打样焊接的左手板两块，实物本来就是 25 mm** ⇒
> ⛔ **不需要重画 PCB**；🔴 **错的是【文档】**（多份现行文档写 20 mm）⇒
> ⭐ **下面"直接后果 = 被取代 / 要重画"那一条【作废】**；⭐ **真正要改的是文档里的尺寸链口径**。
> 📌 画板交接与索引：`files/10-硬件/交接-画板专用对话-20261003.md`

| ⭐ 项 | ⭐ 内容 |
|---|---|
| ⭐ **裁定** | ⭐ **25 mm 为准** —— ⛔ 不是笔误；⭐ 项目文档现行的 **20 mm**（`files/10-硬件/硬件接口总表.md:139-150`）**被取代** |
| ✅🔴 **直接后果（2026-10-03 已更正）** | ⛔ ~~已打样焊接完成的左手板两块（20 mm 口径）被取代 ⇒ 需要重画 PCB~~<br>✅ **更正：实物本来就是 25 mm ⇒ ⛔ 不用重画**；🔴 **要改的是文档**（20 mm 那套尺寸链口径全部作废，⛔ 不是改板子） |
| ⭐ **数值推导** | 8 列轴心跨距 = **7 × 25 = 175 mm**（⭐ 旧口径 140 mm）<br>单块（4 列）轴心跨距 = **3 × 25 = 75 mm** ⇒ ⚠️ 板宽/留边按「**留边之和 = 列间距**」（§二）重算：⭐ 对称留边 **12.5 mm** ⇒ 板宽 ≈ **100 mm** ⇒ ⚠️ **是否仍 ≤100 mm 免费额度要重算** |
| ⚠️ **排间距（⭐ 需你确认）** | ⭐ 原稿写的是 **`25 × 25` 网格** ⇒ **排间距也是 25 mm**（⚠️ 项目现行 **12～15 mm**）<br>🔴 影响：`files/10-硬件/左手区方案.md:219`「排间距取 12~15，不是 6~8」这条**前提变了**；⭐ 且**排间距越大、跨排滑弦越远** ⇒ ⭐ **请确认排间距是否确实跟到 25 mm** |
| 🔴 **连带重算清单** | ⭐ 定位板（16 孔坐标）· 键帽（⭐ 间隙 1 mm ⇒ 键帽外廓可放大到 **~24 mm**）· 外壳/面板 · ⭐ **双模式映射表**（列间距变 ⇒ 滑弦"每半音多少 mm"变）· 霍尔焊盘坐标 · 两板留边/跨缝<br>⭐ 对应项目任务：`files/00-总览/规划待办清单.md:102` `C12`（⭐ 口径要从 **20 改成 25**）· `files/20-代码/已知问题与风险清单.md:56` `K-37` |
| ✅ **轴位数量不变** | 仍是 **2 行 × 8 列 = 16 轴位** ⇒ ⭐ ADC 通道（每板 1 片 `MCP3208` / 共 16 路）**不用改** |
| ⭐ **一个可能的依据**（⭐ 待你确认） | ⭐ 真钢琴**白键中心距约 23.5 mm** ⇒ **25 mm 比 20 mm 更接近钢琴手感**（⚠️ 这是我的**推测**，⛔ 不是你说过的理由） |

### 裁定 2 · ⭐ **键帽透光走「侧刻」**

| ⭐ 项 | ⭐ 内容 |
|---|---|
| ⭐ **裁定** | 键帽主体**不透明**（黑/白 PLA）＋ **侧刻**（凹刻或贯穿）＋ **蓝光经导光柱送到侧壁** |
| ⭐ **与已实测方案的关系** | ⭐ 项目已实测「**下缘开窗 0.6～0.8 mm**」= 「比较清楚」（`files/30-方案决策/决策表/M7_LED演奏指引.md:16`）<br>⇒ ⭐ **建议并存**：下缘开窗管「**哪个键在亮**」，侧刻管「**这个键是什么**」（⭐ 原稿本身也是"主体不透明 + 侧刻可读"这个意思） |
| 🔴 **两个未验证前提** | ① ⭐ **轴体是否带中心导光柱** —— 项目里**仍是待核实项**（`files/10-硬件/左手区方案.md:236`）；⭐ 若只有**下灯位**，光从键帽**下部**进 ⇒ ⭐ 侧壁/侧刻能不能亮**必须打样验证**<br>② ⭐ **侧刻是凹刻还是贯穿** —— 原稿写「凹刻**或者**贯穿」⇒ ⭐ **凹刻（0.4～0.6 mm）不发光**（只是填漆后的可见字符）；**贯穿才发光**（`files/10-硬件/机械与硬件待做任务表.md:62`） |
| ⭐ **要打的样** | ⭐ **1 个轴体 + 1 颗灯 + 1 个侧刻键帽**（⭐ 原稿也要求"先打印实验件确认亮度"）⇒ ⭐ 建议并入排期 `B1`（键帽 v2，10/4） |
| ⚠️ **音名刻哪儿** | ⭐ 项目 A2 是**顶面**凹刻音名（`files/10-硬件/机械与硬件待做任务表.md:36`，⭐ 且已裁定**可刻死**）；⭐ 原稿是**侧面**刻字<br>⇒ ⭐ **建议：顶面刻音名（指腹摸得出）＋ 侧面刻图标/功能（视觉）**，⭐ 二者不冲突 |

---

## 一、⭐ 整体机械架构（原稿）

左手部分 = **两个可独立使用的模块**，可磁吸拼成一个整体。

```text
┌────────────────┐  ┌────────────────┐
│    左手模块 A   │  │    左手模块 B   │
│  ○ ○ ○ ○ ○ ○   │  │  ○ ○ ○ ○ ○ ○   │
└────────────────┘  └────────────────┘
         ↕ 磁吸自由拼接
```

**核心要求**

| # | 要求 |
|---|---|
| 1 | 两块板**可以独立使用** |
| 2 | 可以**磁吸拼成一个整体** |
| 3 | 拼接后**轴中心仍保持统一间距** |
| 4 | **PCB 边界基本就是模块外壳边界** |
| 5 | ⛔ **不希望额外留一个很宽的外壳框**把两块 PCB 隔开 |
| 6 | ⇒ 因此采用**上下三明治结构**最自然 |

**三明治（原稿）**：`键帽` → `上壳/面板` → `PCB` → `下壳/底板`，螺丝固定。

**磁吸的定位**（原稿原话）

> 磁铁主要负责**拼接和定位**，⛔ 不要让磁铁单独承担全部机械剪切力。
> 最好再加 **定位凸台 + 定位槽** —— 这样两块模块拼起来以后
> 不会因为磁铁位置误差发生**横向错位**。

---

## 二、⭐ 先建立统一的轴网格（原稿 · ✅ 已裁定 25 mm，见 §〇-A 裁定 1）

> 轴间距 = **25 mm** ⇒ CAD 里**首先**建立 `25 × 25 mm` 基准网格。

⭐ **一切从网格派生**：轴 · 键帽 · PCB · 外壳 · 拼接面 · 磁铁 · 定位结构。

```text
模块 A                 模块 B

○────○────○────○────│────○────○────○────○
                    ↑
                 拼接基准线
```

⭐ **关键做法**：⛔ **不要从「外壳边缘」去量轴距** —— 应当是
**「轴中心 → 25 mm → 轴中心 → 25 mm → 轴中心」**，然后外壳**再围绕这个轴网格生成**。
这样以后把外壳圆角改掉，也不会把键位搞乱。

> ✅ **这条与项目现行做法完全一致**（⭐ 只是数值不同）：
> `files/10-硬件/左手区方案.md:186-201` §6.2 的「跨缝间距」就是同一个道理 ——
> ⭐ **让两块板的留边之和 = 列间距**，拼接后间距才统一。

---

## 三、⭐ 键帽分三种（原稿）

| 类型 | 原稿定义 | 图示 |
|---|---|---|
| **普通键** | **一个音 = 一个轴 = 一个键帽**；⭐ 键帽可做**比较大的水平圆角**（核心动作是滑弦） | `○` |
| **大键** | **一个音 = 两个或更多轴**（例：E3）⇒ ⛔ 不让两个轴各露一个小键帽，而是**多个轴共同支撑一个大键帽** | `○──────○` / 「\______/」（历史引用，当前未收录） |
| **鼓垫** | ⭐ **直接归入「大键」**（例：BD）⇒ 大面积触发区 | `┌───────────┐ │ BD │ └───────────┘` |

**大键的好处（原稿）**：按压更稳定 · 演奏区域更连续 · 外观更像真正的乐器 · 更适合滑弦。
**鼓垫的好处（原稿）**：大面积触发区比几个小按钮更适合鼓的演奏感觉。

> ✅ **与项目现有需求吻合**：⭐ 鼓垫 / 键盘打鼓见
> `files/00-总览/新需求分析-键盘打鼓与loop转鼓机-20261001.md` ＋ `files/10-硬件/鼓垫.drawio.svg`。
> ⚠️ 但「多轴共撑一个大键帽」在项目里**还没有对应任务**（⭐ 见 §十一）。

---

## 四、⭐ 钢琴区单独设计（原稿）

钢琴模式**不强行使用普通圆润键帽**，直接按钢琴的视觉语言做：

```text
白键  白键  白键  白键
┌───┬───┬───┬───┐
│   │   │   │   │
└───┴───┴───┴───┘
   ██      ██
   ██      ██
   黑键    黑键
```

⭐ **但机械结构仍遵循轴网格**（原稿 25 mm；⚠️ 项目实际见 §十-1）——
即：**外观模仿钢琴，机械布局仍服从 PCB/轴网格**。

| 件 | 材料（原稿） | 理由 |
|---|---|---|
| 白键 | **纯白 PLA** | — |
| 黑键 | **黑 PLA** | ⭐ 这样大理石白外壳**不会和白键融成一片** |

> 🔴🔴 **项目硬约束（⭐ 优先级高于原稿）**：⛔ **绝不引入键帽高度差** ——
> 定位**只能靠颜色 / 纹理 / 刻印 / LED**（`files/10-硬件/机械与硬件待做任务表.md:70` A9 ·
> `files/30-方案决策/当前方案总览.md:29`）。
> ⭐ 理由已实测：**黑键高出白键 ~10 mm ⇒ 钢琴上根本无法从 C 滑到 D**。
> ⇒ ⭐ **原稿的「钢琴式键帽」必须理解为「等高等距 + 黑白配色」**，⛔ 不是真钢琴的立体黑键。

---

## 五、⭐ 键帽透光（原稿）

原稿前提：**轴体本身有导光柱** ⇒ 不用考虑「LED 能不能直接穿透整个键帽」。

```text
       键帽
┌────────────────┐
│       C        │ ← 侧刻
└───────┬────────┘
        │  导光柱
      0603 LED
```

**原稿建议**

| # | 建议 |
|---|---|
| 1 | 字/图标直接做成**凹刻或者贯穿** |
| 2 | 键帽主体可以是不透明**黑 PLA** |
| 3 | **蓝光从内部通过导光柱送到侧刻** |
| 4 | ⛔ 不额外购买透明耗材 |
| 5 | ⭐ **先打印实验件确认亮度** |
| 6 | ⭐ 蓝色 0603 LED 本身就可以成为**统一的视觉元素** |

> ⚠️ **与项目已定口径的差异见 §十-5**（项目已实测的是「**下缘开窗**」，不是「侧刻」）。

---

## 六、⭐ 颜色体系（原稿）

| 类别 | 颜色 | 用途 |
|---|---|---|
| **实体材料** | 🩶 **白色大理石 PLA** | 外壳 |
| | ⚫ **黑 PLA** | 黑键、指板、控制件 |
| | ⚪ **白 PLA** | 钢琴白键 |
| **电子视觉** | 🔵 **蓝色 LED** | 键帽 / 状态光 |
| **模型漆** | ⚫ 黑 · ⚪ 白 · 🟠 橙 | **凹刻图标填色** |

**模型漆填色规则（原稿）**：普通文字/图标 → **白色**；需要强调的操作 → **橙色**；LED 状态 → **蓝色**。

> ⭐ 原稿结论：**不要再为了外观买一堆彩色 PLA**。
> ⭐ 整台琴的颜色实际上就是：**白大理石 + 黑白 + 蓝光 + 少量橙色**。
> ✅ **与项目一致**：`files/10-硬件/机械与硬件待做任务表.md:70` A9 已列「黑键位涂深色」。

---

## 七、⭐ 图标不要在 SolidWorks 里手描（原稿）

**统一走这条路**：

```text
SVG  →  SolidWorks 草图  →  拉伸切除  →  模型漆填色
```

**图标参数（原稿）**

| 项 | 值 |
|---|---|
| 图标尺寸 | 约 **5～10 mm** |
| 最细线宽 | 尽量 **≥ 0.6 mm** |
| 凹刻深度 | 约 **0.3～0.5 mm** |

⭐ 理由：这样 **A1 打出来比较稳**，后面填模型漆也舒服。

> ⚠️ **与项目已有参数取交集**（见 §十-7）：项目 A2 定的是**刻深 0.4～0.6 mm / 字号 5～6 mm**
> ⇒ ⭐ **建议取值：刻深 0.4～0.6 mm · 字号 5～6 mm · 最细线宽 ≥ 0.6 mm**。

---

## 八、⭐ 轴体模型不要自己画（原稿）

**优先找 STEP**（⛔ 不要自己画轴体）：

| 来源 | 主要找什么 | 链接 |
|---|---|---|
| **KiSwitch** | Cherry MX / Kailh / Choc / 其他键轴 | https://github.com/kiswitch/kiswitch |
| **Keychron Hardware Design** | 轴体 / 键帽 / 稳定器 / 编码器 / 其他机械结构 | https://github.com/Keychron/Keychron-Keyboards-Hardware-Design |
| **CommunityCAD** | 各种标准件与键盘相关 CAD | https://communitycad.dev/ |

⭐ 原稿判断：**只为在 SolidWorks 里占位、确定键帽与导光柱的位置 ⇒ STEP 已经完全够用**。

> 🔴🔴 **但原稿自己补了一句，⭐ 而这句对本项目是决定性的**：
> 「你实际建模时最好还是以**你手里的实际轴体型号**为准。特别是你这个项目依赖导光柱，
> 轴体顶部的尺寸和导光柱位置**最好不要拿「差不多的 Cherry MX」代替**。」
>
> ⭐ **本项目正是这个情况**（见 §十-2）：项目用的是**磁轴**，
> ⛔ 而且**型号还没定**、**底座外廓还没量** ⇒ ⭐ **上面这些 STEP 只能当"占位块"，⛔ 不能当接口尺寸**。

---

## 九、⭐ 推荐的建模顺序（原稿 · 12 步）

> ⭐ 原稿强调：**不要从外壳开始画。**

```text
① 实际轴体 STEP
        ↓
② 建立轴网格
        ↓
③ 放置所有轴
        ↓
④ 确定普通键 / 大键 / 钢琴键 / 鼓垫
        ↓
⑤ 确定两块 PCB 边界
        ↓
⑥ 确定模块拼接基准线
        ↓
⑦ 设计磁吸 + 定位结构
        ↓
⑧ 设计上壳
        ↓
⑨ 设计下壳
        ↓
⑩ 设计键帽
        ↓
⑪ 加侧刻/图标
        ↓
⑫ 最后处理圆角、外观细节
```

> ⭐ 原稿警告（照录）：
> **不要先把大理石外壳画得很漂亮，然后发现 PCB、轴距、磁铁位置塞不进去。** 😂

⭐ **与项目排期的对齐**（`files/00-总览/国庆安排-PCB与模型-20261001.md` §B-3）：
① = **B0**（量实物：磁轴底座外廓 ＋ 两板实际板框/跨缝）· ②③④⑩ = **B1**（键帽 v2）·
⑤⑥ = **B0/D1** · ⑧⑨ = **B5**（整机外壳/面板）· ⭐ ⑦（磁吸）**项目里还没有对应任务**。

---

## 十、🔴🔴 与项目现有事实的对照（⭐ 建模前必须逐条过）

> ⭐ **判据一律以实物测量为准**；下表「项目现有事实」列都带出处，⭐ 可直接点回去核。

| # | 原稿说法 | ⭐ 项目现有事实（出处） | ⭐ 处置 |
|---|---|---|---|
| **1** | 🔴 **轴间距 = 25 mm**，建 `25 × 25` 网格 | ⭐ **列间距 = 20 mm**（2026-09-13 由 15 → 20 改口径）：`files/10-硬件/硬件接口总表.md:139-150` —— 跨缝 **20** · 对称留边**各 10** · **8 列轴心跨距 = 7 × 20 = 140 mm** · 板宽 **~100 mm/块**；⭐ 且**左手板两块已打样焊接完成**（`files/00-总览/国庆安排-PCB与模型-20261001.md:5`）<br>⚠️ 旧值 15/105/~60 仍散落多份文档（`files/20-代码/已知问题与风险清单.md:56` `K-37`；重算任务 `files/00-总览/规划待办清单.md:102` `C12`） | ✅ **已裁定 = 25 mm（新方案，重画板）** ⇒ ⭐ **见 §〇-A 裁定 1**（⭐ 含连带重算清单；⚠️ 20 mm 口径与已打样左手板**被取代**） |
| **2** | 按 **Cherry MX / Kailh / Choc** 找轴体 STEP | ⭐ 项目用的是**磁轴**（线性、MX 兼容底座）：`files/10-硬件/左手区方案.md:36`；⭐ **只有 2 个定位脚、没有电气引脚** ⇒ ⛔ **不需要热插拔轴座**（`files/10-硬件/采购与验证清单.md:350`）；⭐ **霍尔焊盘在轴中心正下方**（`files/10-硬件/左手板原理图评审.md:270`）<br>🔴 **型号仍未定**（`files/30-方案决策/硬件选型表.md:1564` B2）＋ 🔴 **底座外廓未实测**（`files/10-硬件/机械与硬件待做任务表.md:90` C3） | ⭐ **STEP 只作占位**；⛔ 键帽内孔 / 轴心接口**必须等量完实物**（= 排期 **B0**） |
| **3** | 三明治 = **上壳/面板 + PCB + 下壳** | ⭐ 项目另有**第四层**：**上方一块整体的 3D 打印定位板**统一固定 16 个轴（`files/10-硬件/左手区方案.md:207`）—— ⭐ 这是「分板不卡手」的**前提**<br>🔴 **且实测有坑**：**装了定位板后磁轴行程只剩 1/3**（0.20 V / 248 码 vs 不装 0.60 V / 744 码）⇒ **已建那版定位板的高度很可能要改**（`files/00-总览/国庆安排-PCB与模型-20261001.md:145`） | ⭐ 结构按**四层**画：`键帽 / 定位板 / PCB / 下壳`；<br>🔴 **定位板高度必须重定**（= 排期 **B3**） |
| **4** | **磁铁**负责模块拼接与定位 | ⚠️ 项目里**小磁铁已「降为可选/兜底」**（因为自制拨弦件被否）：`files/10-硬件/采购与验证清单.md:351`<br>⛔ 且**禁用铁质螺丝 / 钢定位板**（磁铁会吸）⇒ 铝 / 黄铜 / 尼龙 / PLA（`files/00-总览/国庆安排-PCB与模型-20261001.md:163`） | ⚠️ 若要做磁吸拼接 ⇒ **要把磁铁提回采购单**（⭐ 原稿的「定位凸台 + 定位槽」也应一起做） |
| **5** | 透光走**侧刻**（键帽主体不透明黑 PLA） | ⭐ 项目已确认轴体是**下灯位导光柱**、效果为**键帽下部发光（⛔ 不是字符发光）**：`files/10-硬件/LED演奏指引方案.md:9-10`、`:303-318`<br>⭐ 且**已实测**：「把键帽下面一部分切掉透光 → **比较清楚**」⇒ **下缘开窗 0.6～0.8 mm** 是已定方案（`files/30-方案决策/决策表/M7_LED演奏指引.md:16`）<br>⚠️ **「轴体是否带中心导光柱」仍列在待核实**（`files/10-硬件/左手区方案.md:236`） | ✅ **已裁定 = 侧刻**（⭐ 建议与已实测的「下缘开窗」**并存**）⇒ ⭐ **见 §〇-A 裁定 2**（⭐ 含两个未验证前提）<br>⭐ LED 本身**已定**：**单色 × 16 颗 + `TLC5916ID`**（`files/10-硬件/采购与验证清单.md:14-19`） |
| **6** | 白大理石 PLA 外壳 + 黑/白 PLA 键帽 | ⚠️ **「大理石」这个材料在本文之前全仓零命中**（grep 无）⇒ ⭐ **属新增**<br>⚠️ 材料仍是 **PLA/PETG/ABS 待定**（`files/30-方案决策/硬件选型表.md:461` K4）<br>⛔ 但「黑白键」**只能用颜色/纹理/刻印/LED，绝不能用高度差**（见 §四） | ✅ **可以采纳**（⭐ 与原稿不冲突）；<br>⭐ 记：**外观材料这一项从"待定"变成"倾向白色大理石 PLA"** |
| **7** | 图标 5～10 mm · 线宽 ≥0.6 · 凹刻 **0.3～0.5** mm | ⭐ 项目 A2 定的是**刻深 0.4～0.6 mm**、**字号 ≈ 5～6 mm**（`files/10-硬件/机械与硬件待做任务表.md:36`）<br>⭐ 且 A2 的联动冲突**已裁定为八度级** ⇒ **音名可以刻死** ✅（`files/00-总览/国庆安排-PCB与模型-20261001.md:138`） | ✅ **取交集**：刻深 **0.4～0.6 mm** · 字号 **5～6 mm** · 线宽 **≥0.6 mm** |
| **8** | 「A1 打出来比较稳」 | ⚠️ 项目记录是 **Bambu A1（自有）**（`files/30-方案决策/硬件选型表.md:469`），而排期写的是**收假回实验室打**（`files/00-总览/国庆安排-PCB与模型-20261001.md:164`） | ⚠️ **请确认是不是同一台**（⭐ 若是，参数可直接按 A1 定） |
| **9** | 只讲左手两模块 | ⭐ 项目**右手区还有结构件**：拨片 / 摇杆 / 推子固定件（`files/00-总览/国庆安排-PCB与模型-20261001.md:139` B-2） | ⭐ 本文档**不覆盖右手区** ⇒ ⭐ 右手区仍按 `B2` 走 |

### 10-附 · ⭐ 与原稿**完全一致**的几条（可以放心照做）

| 原稿 | 项目出处 |
|---|---|
| PCB 边界 = 模块边界 · ⛔ 不要宽外壳框 | `files/10-硬件/左手区方案.md:186-201`（跨缝 = 列间距；留边各 10 mm 用来放 ADC/连接器/螺丝孔） |
| 拼接后轴中心必须保持统一间距 | 同上 §6.2「跨缝间距」 |
| ⛔ 不要从外壳边缘量轴距 | `files/10-硬件/左手区方案.md:207`（分板前提 ①：轴位由**统一零件**保证） |
| 普通键要大水平圆角（滑弦） | `files/10-硬件/机械与硬件待做任务表.md:35` A1（**划过顺滑的第一要件**） |
| 鼓垫 = 大面积触发区 | `files/10-硬件/鼓垫.drawio.svg` · `files/00-总览/新需求分析-键盘打鼓与loop转鼓机-20261001.md` |
| 先做小样板，⛔ 不要先画漂亮外壳 | `files/00-总览/国庆安排-PCB与模型-20261001.md` §B-0（零依赖前置活） |

---

## 十一、⭐ 原稿点名的「五个小样板」—— 落到项目任务号

> ⭐ 原稿最后一句：最值得先做的**不是外壳**，而是
> **「轴网格 + 实际轴体 STEP + 一个普通键帽 + 一个大键 + 一个钢琴白键/黑键」**。
> ⭐ 这五个东西一旦确定，后面的外壳基本就是围着它们长出来的。

| # | 小样板 | ⭐ 项目对应任务 | 状态 |
|---|---|---|---|
| **1** | 轴网格（25 / 20 mm） | ⭐ `B0`（量实物：底座外廓 ＋ 板框 ＋ 跨缝）＋ 🔴 本文 §十-1 裁定 | ⬜ **卡裁定** |
| **2** | 实际轴体 STEP | 🔴 `C3`（量底座外廓）＋ `硬件选型表.md:1564` B2（型号待定） | ⬜ **卡实物** |
| **3** | 一个普通键帽 | ⭐ `B1` 键帽 v2（圆角 ＋ 刻音名 ＋ 下缘开窗），排期 10/4 | ⬜ |
| **4** | **一个大键**（多轴共撑） | 🔴 **无对应任务** ⇒ ⭐ **建议新增** | 🔴 **缺** |
| **5** | **一个钢琴白键 / 黑键** | 🔴 **无对应任务**（现有 A9 只到「黑键位涂深色」）⇒ ⭐ **建议新增** | 🔴 **缺** |

> ⭐ **推论**：原稿的 ① ② ③ 项目已在做（`B0`/`C3`/`B1`），
> 🔴 但 **④ 大键 与 ⑤ 钢琴键帽是全新的** —— 它们要不要做、什么时候做，⭐ **需要拍板**。

---

## 十二、⭐ 原稿给的网址（按用途归类）

| 用途 | 站 | 链接 |
|---|---|---|
| **图标（首选）** | Lucide Icons（统一线性 SVG） | https://lucide.dev/icons/ |
| 图标（备选） | Material Symbols | https://fonts.google.com/icons |
| 图标（备选） | Font Awesome | https://fontawesome.com/icons |
| PNG → SVG 描摹 | Inkscape（Bitmap Trace） | https://inkscape.org/ |
| **轴体 CAD（首选）** | KiSwitch | https://github.com/kiswitch/kiswitch |
| 键盘 CAD | Keychron Hardware Design | https://github.com/Keychron/Keychron-Keyboards-Hardware-Design |
| 标准件 CAD | CommunityCAD | https://communitycad.dev/ |

> ⚠️ **以上均为外链、未经本项目验证**；⭐ 引用时以「**占位**」为目的，⛔ 不作为接口尺寸依据（见 §八）。

---

## 十三、⭐ 一句话

```text
⭐ 原稿的价值 = 把「外壳怎么长出来」讲清了：轴网格 → 轴 → 键帽分类 → PCB 边界 → 拼接 → 磁吸 → 壳。
✅ 2026-10-02 裁定：① 轴间距 25 mm（新方案，要重画板 ⇒ 取代 20 mm 口径与已打样左手板）
                  ② 键帽透光走侧刻（⭐ 与已实测的「下缘开窗」并存）
🔴 由此推出的必做：C12 尺寸链按 25 mm 重算 · ⚠️ 排间距是否也 25（待确认）· 定位板/键帽/外壳/映射表全重算
⭐ 另有【两件全新的】项目里还没有任务：大键（多轴共撑）· 钢琴白/黑键帽。
```
