hokuu1102/Gowin2026-PolySynth/files/20-代码/ESP32侧回复-BLE根因与下行贯通-20261014.md

# ESP32 侧回复：BLE 服务发现根因 + 下行链路已贯通（2026-10-14）

> **回话对象**：「FPGA2026-esp32/files/20-代码/上板问题清单-20261013.md」（历史引用，当前未收录）
> **回话人**：ESP32 线
> **工作树**：`C:\Users\hokuu\Desktop\FPGA\FPGA2026-esp32`（分支 `feat/s3-ble`）
> **状态**：BLE 缺陷已修（根因已定位）；下行链路经你们确认已贯通

---

## 一、先谢你们那条撤销

你们 `上板问题清单-20261013.md` 第 161 行撤销了 **P4「ESP32 灌曲谱没声音」**，
依据是用户现场更正："esp32 能发送曲谱然后发音，不用排查这个了"。

你们给的下行链路（第 171 行）我方**记下了**：

```
ESP32 → G22 → u_uart_rx_esp → u_evt_uart_rx(0xA5 9字节帧)
      → u_evt_buf → u_play_seq → seq_arb → note_manager
```

**这对我们很值**：此前我方只能验到「UART1 出口的字节与灌进去的一致」
（`_uart1_wire_check.py`，判据是逐字节比对），
⭐ **现在第一次有了「声音」这个终点判据** —— 这是端到端贯通。

📌 我方已在交接文档里把这条记为**首个端到端证据**，
⛔ 不再写「只验到字节层」。

---

## 二、我方本轮修的一个真缺陷（与你们无关，但值得记）

### 症状

PC 连上 ESP32 后，**只能发现 4 个 GATT 强制特征**
（`2a05` 服务变更 / `2a00` 设备名 / `2a01` 外观 / `2aa6` 中央地址解析），
**我方自己的 `0xABF1`~`0xABF4` 一个都没有** ⇒ 所有 BLE 工具全线失败。

### 排查过程（每步都有判据）

| # | 尝试 | 结果 |
|---|---|---|
| 1 | 板子自证 | 属性表创建 + 句柄 40/42/44/47/49 + `service started` **全部正常** |
| 2 | 板子复位 / 重烧固件 | 无效 |
| 3 | 改设备名 | 能扫到了，**但服务表还是 4 个** |
| 4 | 延长等待（1/3/6 秒） | 无效 |
| 5 | 强制 UNCACHED（bleak 的 `winrt={"use_cached_services": False}`） | 仍是 4 个 |
| 6 | 广播包加入服务 UUID（AD type `0x03`） | 广播侧正确宣告 `0xABF0`，连上仍 4 个 |
| **7** | 加日志记录**【客户端读了哪些句柄】** | **板子收到的 ATT 请求 = 0 条** |
| **8** | **对照实验：同一台 PC 连另一个 BLE 设备** | **能正常发现它的自定义服务（`fe55`）** |
| 9 | 发 GATT Service Changed 指示（`0x2A05`） | 返回 `ESP_OK`，但服务表没变 |

### 根因

**Windows 按【MAC 地址】缓存 GATT 服务表**，
认定"这个设备只有 4 个服务"，于是**根本不发起服务发现**
（第 7 条证据：ATT 请求 0 条）。

⚠️ **改设备名绕不过它** —— 因为**缓存键是 MAC，不是名字**。

### 修法

广播地址由**出厂 public 地址**改为**随机静态地址**：

```
94:A9:90:2D:A6:62   →   C2:AA:20:26:00:01
```

- `.own_addr_type`: `BLE_ADDR_TYPE_PUBLIC` → `BLE_ADDR_TYPE_RANDOM`
- 启动时调 `esp_ble_gap_set_rand_addr()`
- 用**固定值**而不是每次随机 ⇒ 重启后地址不变，便于日志比对

**验证**：`0xABF*` 从 **0 个 → 4 个** ✅

### 顺带修的一处

`CONFIG_BT_GATTS_SEND_SERVICE_CHANGE_MODE` 由 `AUTO` 改 `MANUAL` ——
否则 `esp_ble_gatts_send_service_change_indication()` 会被协议栈拒绝
（日志原文：`can't send service change indication manually,
please configure the option through menuconfig`）。

⭐ 保留它的价值：**将来改 GATT 结构时客户端能自动重新发现**，⛔ 不必再清缓存。
已同步进 `sdkconfig.defaults`。

### ⚠️ 给你们的提醒（如果你们那边也要接 BLE）

你们的板子如果换固件后 PC 认不出服务，**先怀疑这个 MAC 缓存**，
⛔ 不要先去查 RTL。判据：**看板子收到的 ATT 请求是不是 0 条**。

---

## 三、当前真机状态

| 项 | 状态 |
|---|---|
| BLE 服务发现 | **已修**（`0xABF*` 4 个全部发现） |
| 读 `0xABF4` | 正常（361 字节，八组齐全） |
| 屏状态机 / 屏曲名 | 通过 |
| 异常路径 / 循环压力 | 通过 |
| 离线全量 | 24 个工具，612 项 OK，0 项 RED |
| **ESP32 → FPGA 出声** | **你们已确认贯通** ✅ |
| FPGA → ESP32 回传 | 等你们实现 14 B 实时事件帧 |

⚠️ **3 项失败，⛔ 不是代码问题**：
`命令与上行回归` / `下行线上字节级校验` / `上行闭环逐字节校验`
—— 全依赖 CH340 假 FPGA，实测"一个字节都没收到"
⇒ CH340 的 `RX` 未接到 ESP32 的 `GPIO17` 或未共地（换线时碰到了）。

---

## 四、我方仍在等你们的一件事

**上行的 9 B 回传帧改成 11 B**（类型码 `0x20` + 校验）——
这是你们 2026-10-13 答复里定的，我方已接受并实现了解析侧的预留。

⛔ 不阻塞我方；你们按自己的排期做即可。

---

## 附 · 引用的事实索引

| 事实 | 出处 |
|---|---|
| P4 撤销、下行链路 | `上板问题清单-20261013.md` §P4（第 161/171 行） |
| 9 B 回传帧改 11 B | `FPGA侧答复-9B回传帧类型码-20261013.md` §一 |
| 上行帧格式 v1.1 | `FPGA侧答复-ESP32再回函-20261001.md` §四 |
