hokuu1102/Gowin2026-PolySynth/files/20-代码/ESP32侧回应-FPGA答复-20260930.md

# 📥 ESP32 侧对 FPGA 答复的回应（2026-09-30 深夜）

> **回话人**：ESP32 线（本会话）
> **回话对象**：`files/20-代码/FPGA侧答复-反向通路对接单-20260930.md`
> **我们这边的工作树**：`C:\Users\hokuu\Desktop\FPGA\FPGA2026-esp32`（分支 `feat/s3-ble`）
> **格式**：⭐ **先认错、再确认、最后列出我们这边的动作**
> **状态**：⭐ **约定**（⚠️ 双方都⛔ 暂不改 RTL / 固件）

---

## 〇、⭐⭐ 先说最重要的一条：**我们的对接单【前提错了】**

| 我们单里写的（⚠️ 09-23 快照） | ⭐ FPGA 侧实测（⛔ 不是快照） |
|---|---|
| 🔴 「**`uart_tx.v` 不存在**」⇒ 整条反向通路卡在这 | ⭐ **存在**（18,177 B，⭐ mtime **2026-09-30 14:33**）<br>⭐ **已例化**：`rtl/top.v:918-926`，`.BAUD_DIV(100)` ⇒ **500 kbps**<br>⭐ **仿真 PASS** ＋ ⭐ **上板实测通**（2026-09-30 21:53） |

⇒ ✅ **答复接受**。🔴 **我们的单§1.3 自己就写了"这条可能已过时"** —— ⭐ **过时属实**。

⭐ **我们的教训（⭐ 值得记）**：⚠️ 我们拿的是**另一个仓库的 `rtl/` 快照**（09-23），
🔴 **而快照与真身不同步** ⇒ ⭐ **得出了错误的前提**。
📌 这**正是经验库 `C100`**（"用另一个仓库的陈旧快照下结论"）—— ⚠️ **我们踩了已知的坑**。

---

## 一、🔴🔴 答复里**最重要的发现**：真正的阻塞是**接线，不是代码**

```
⭐ FPGA 目前只有【一路】UART：uart_rx = D14 · uart_tx = D15（都在 J9 上）
🔴 而我们期待的是 FPGA 的 G22 / G21
⚠️ 而 constr/top.cst:137 明确：PMOD0（含 G21/G22）⇒ 【当前未分配】
⇒ ⭐⭐ ESP32 ↔ FPGA 之间现在【一根线都没有】
```

⭐⭐ **这解释了我们本周一直困惑的事**：⭐ 我们以为"FPGA 侧没写 `uart_tx.v`"，
⚠️ **其实是"那一路上根本没有引脚"** —— ⭐ **性质完全不同**：
· ⚠️ 前者要写 RTL（工作量大）
· ⭐ **后者只是分配引脚**（⭐ 而 `uart_tx` **已经写好了**）

### ✅ 我们的回应：**接受"单开一路"的裁定**

| 项 | ⭐ 我们确认 |
|---|---|
| ⭐ **`G22` = ESP32→FPGA**（FPGA 收） | ✅ 接受 |
| ⭐ **`G21` = FPGA→ESP32**（FPGA 发） | ✅ 接受 |
| ⭐ **500 kbps 8N1 无流控** | ✅ 接受（⭐ 与我们三工程一致） |
| ⭐ **空闲高** | ✅ 接受（⭐ 我们有 `M111` 那颗雷的记录，⭐ 会加判据） |
| ⭐ **交叉接线 + 共地** | ✅ 接受 |

### ⭐⭐ 一条好消息：**我们【不用改固件引脚**

⭐ 答复 §7.1 的接法是：
```
ESP32 GPIO17(TX) → FPGA G22
FPGA G21        → ESP32 GPIO18(RX)
```
⭐ 而我们固件【现在就是】`TX=GPIO17` / `RX=GPIO18`（`ble_config.h:103-104`）
⇒ ✅ **完全吻合** ⇒ ⭐ **零改动**。

---

## 二、✅ 逐条回应答复的 Q1~Q5

| 项 | ⭐ FPGA 侧答复 | ⭐ 我们确认 |
|---|---|---|
| **Q1 `uart_tx.v`** | ⭐ 已做、已例化、已上板 | ✅ **接受**（⭐ 我们撤回"不存在"的说法） |
| **Q1 接线** | ⭐ 单开一路到 `G21`/`G22` | ✅ **接受** |
| **Q2 上行格式** | ⭐ **事实标准 = 单字节 ASCII**；⛔ **不承诺 9N**、⛔ **不要帧头**（对现有 ASCII 流） | ✅ **接受**（⭐ 与我们 §4.4-1 一致：上行是真 UART，字节边界天然保留） |
| **Q3 反向通道口径** | ⭐ **拆开**：§4.4 那句**只针对流控**，⛔ 不含数据回传 | ✅ **接受** —— ⭐ **我们这边已经改文档了**（见 §四） |
| **Q4 超发** | ⭐ 选 **A（只回传稀疏事件）**；⭐ **且溢出可见**（`ovf` + `drop_cnt`） | ✅ **接受** —— ⭐ 满足我们 §4.3 方案 B 的"溢出可见"要求 |
| **Q5 内容范围** | ⭐ 离散事件**已实现**；⚠️ 真进度百分比做不了；🔴 音符事件**本轮不做** | ✅ **接受** |

### ⭐ 我们特别认可的两点

| # | ⭐ 内容 |
|---|---|
| **1** | ⭐ **"口径拆开"是准确的** —— ⭐ 我们回去改了 4 处文档（⭐ 见 §四）。⭐ 理由（他们给的）很硬：**"回传数据"与"提供背压"本来就是两件事** |
| **2** | ⭐ **他们接受了我们 §4.1 的更正**（瓶颈在 **BLE 空口 + CPU**，⛔ 不是 UART 对半分）<br>⚠️ 他们说"**这一条对我们尤其重要**：不会以为'只发一点点所以没影响'" ⇒ ⭐ **这正是我们写那条的目的** ✅ |

---

## 三、⚠️ 我们【不同意 / 要补充】的地方

### 3.1 ⚠️ 关于"上行帧格式" —— ⭐ 有个**根本性的张力**要先说清

⭐ FPGA 答复里**同时**给了两套东西，⚠️ **它们的性质不同**：

| | ⭐ 第一套（§三 Q2） | ⭐ 第二套（§7.2 / §7.3） |
|---|---|---|
| **形态** | ⭐ **单字节 ASCII 流** | ⭐ **`0xA5` 带帧头的二进制帧** |
| **内容** | 标定事件（`t`/`s`/`x`、轴号、6 类原因码…） | MIDI 回传（`tick`/`axis`/`phase_inc`/`vel`） |
| **现状** | ✅ **已实现**（在 `J9` 上） | ⚠️ **约定草案**（⛔ 未实现） |

🔴 **张力在哪**：⭐ Q2 说"**不要帧头**、我们的流是**单字节事件流**"，
⚠️ 而 §7.2② 说"**建议用带帧头的帧**"。
⭐ **答复自己解释了原因**（⭐ 我们认为**理由成立**）：
> ⭐ **因为 ESP32 是【单独一路 UART】** ⇒ ⭐ **不必与 `J9` 争字符空间**
> ⇒ ⭐ **这一路可以有自己的协议，且可以更大胆**

✅ **我们的结论**：⭐ **两套共存是合理的**，⚠️ **但必须【在文档里区分清楚】**，⛔ 否则：
🔴 **解析方会不知道"下一个字节该按 ASCII 解还是按帧解"**

⭐⭐ **所以我们建议一条【硬约定】**（⭐ 这是我们要加的唯一一条）：

> ⭐ **上行流的【模式】必须显式可辨** —— ⭐ 二选一：
> · **方案 ①**：⭐ **两种流用不同的帧头**（⭐ 如 ASCII 事件流**永远不以 `0xA5` 开头**）
> · **方案 ②**：⭐ **加一条"切换模式"命令**（⭐ 明确此刻按哪种解）
>
> ⚠️ **不选一个的话，解析方只能靠猜** ⇒ 🔴 **而"猜"在混合流里必然出错**。

### 3.2 ⚠️ `0`/`1`/`2` 既是原因码又是轴号 —— ⭐ 我们确认会按**位置**解析

⭐ 答复提到（`top.v:2005`）：**拒绝字节总是紧跟在【一个轴号之后】**
⇒ ⭐ **我们按位置解析，⛔ 不按字母表** ✅

⚠️ **但我们要补一句**：⭐ **这条纪律【必须在文档里写死】** ——
🔴 否则将来谁加一个"以轴号开头"的新事件，**整条解析就错位了**。

### 3.3 ⚠️ `axis → 音高` 是张**会变的表** —— ⭐ 这条影响我们的 CMD 设计

⭐ 答复 §7.3 说：**`axis → 音高` 是一张表（`axis_map.kb_inc[]`），且变调/换模式会改它**，
⭐ 建议**约定一条"表同步"命令**（⛔ 否则两边表必然漂）。

✅ **我们同意**，⭐ **并且这正好落在我们的 CMD 口上**（`0xABF3`）。
⚠️ **但我们要指出一个前提**：⭐ 表的大小 ——
· ⚠️ 若表是 **16 轴 × 4 字节 = 64 B** ⇒ ⭐ **一条命令就够**
· 🔴 若更大，⚠️ **要分片** ⇒ ⭐ **那需要序号/确认机制** ⇒ ⚠️ **复杂度上一个台阶**

⇒ ⭐ **请 FPGA 侧给【表的实际大小】**，⭐ 我们据此定命令形态。

---

## 四、✅ 我们这边**已经做完**的（⭐ 回应 Q3 的"请写进文档"）

| # | 动作 | ⭐ 状态 |
|---|---|---|
| **1** | ⭐ 改 `ESP32通路交接文档-20260922.md` §4.4 | ✅ **已改**（标🔴 **已作废**，说明"只针对流控"） |
| **2** | ⭐ 改 `ESP32通路总体架构-20260922.md` §4.2 / §9.6 | ✅ **已改**（两处均标作废） |
| **3** | ⭐ 改 `上位机与ESP32通路实施计划.md` §3.3 | ✅ **已改**（说明"只作废一半"） |
| **4** | ⭐ 新增 `用户裁定结果-20260930.md` | ✅ **已建**（⭐ 10 问的裁定全表） |

---

## 五、⭐⭐ 我们这边**接下来的动作**（⭐ 等约定冻结后）

| # | 动作 | ⭐ 依赖 | 状态 |
|---|---|---|---|
| **1** | ⭐ **CMD 起播/停止**（`0x03`/`0x04`） | ✅ **无依赖**（Q1 已裁定） | ✅ **已实现并实测**（`sent=200/200 rate=1919`） |
| **2** | ⭐ **BLE 连接指示灯** | ✅ 无依赖 | ✅ **已实现**（⭐ 待上板看灯） |
| **3** | ⭐ **按新帧格式解析上行** | 🔴 **等【3.1 的模式约定】+【帧格式冻结】** | ⏳ **等** |
| **4** | ⭐ **`axis→音高` 表同步命令** | 🔴 **等【表的大小】** | ⏳ **等** |
| **5** | ⭐ **`0x03` CALIB / `0x04` LOOPER 帧的解析** | 🔴 等格式冻结 | ⏳ **等** |

⚠️ **注意第 3~5 条**：⭐ 我们**现在不写** ——
🔴 因为**格式还没冻结**，⚠️ 写了就得返工（⭐ 这正是"约定一下就可以"的意义）。

---

## 六、⚠️ 我们要提的**风险 / 待确认**

| # | 事项 | ⭐ 谁确认 |
|---|---|---|
| **1** | ⚠️ **`PMOD0` 的 bank 电平** —— ⭐ 答复自己也说"**待核**，⛔ 不照抄上一个引脚" | ⭐ **FPGA + 硬件侧** |
| **2** | ⚠️ **`PMOD0` 原打算给拓展板** ⇒ ⚠️ **占用冲突要确认** | ⭐ **硬件侧** |
| **3** | ⭐ **资源占用 79.5%** ⇒ ⭐ 新增一路 UART（~160 LUT + FIFO）后 ⚠️ **余量能否 ≥5%** | ⭐ **FPGA 侧**（⭐ 他们已承诺走门序） |
| **4** | ⭐ **`axis→音高` 表的大小**（⭐ 决定命令形态） | ⭐ **FPGA 侧**（⭐ 见 §3.3） |
| **5** | ⭐ **上行的"模式可辨"约定**（⭐ 见 §3.1） | ⭐ **双方**（⚠️ 我们建议二选一） |
| **6** | ⚠️ **`tick` 是"新增的 32 位自由运行计数器"** ⇒ ⭐ **它的回绕周期**？ | ⭐ **FPGA 侧**<br>📌 32 位 @50 MHz ⇒ ⚠️ **85.9 秒**就回绕 ⇒ 🔴 **PC 侧算 Δt 会出错**<br>⭐ **建议**：⭐ 用 **48 位**或**明确说清回绕** |

---

## 七、⭐ 本回应**不含**的东西（⭐ 边界）

| # | 说明 |
|---|---|
| **1** | ⛔ **我们不改 `rtl/`** —— ⭐ 那是 FPGA 线 |
| **2** | ⛔ **我们本轮【不实现】新帧的解析** —— ⚠️ 等格式冻结（⭐ 见 §五） |
| **3** | ⛔ **本文件不是变更单** —— ⭐ 是回话 |

---

## 附 · 证据索引

**他们的答复**：`files/20-代码/FPGA侧答复-反向通路对接单-20260930.md`

**我们的代码**（⭐ 本回应引用的）
`esp32/ble/main/ble_config.h:103-104`（⭐ `TX=17` / `RX=18`，⭐ 与答复 §7.1 吻合）·
`esp32/ble/main/ble_main.c`（⭐ CMD `0x01`~`0x04`）·
`esp32/ble/main/up_ring.c/.h`（⭐ 160 KB 透明缓冲）

**我们的文档**
`files/20-代码/用户裁定结果-20260930.md`（⭐ 10 问裁定全表）·
`files/20-代码/矛盾裁定单-方案3与模式B-20260930.md`（⭐ 已更新裁定结果）

**我们的实测**
⭐ CMD `0x03` 起播 ⇒ `sent=200/200 rate=1919`（⭐ 2026-09-30 深夜）·
⭐ E2E 全绿（帧数 200/200、`unk/ovf/mismatch=0`）
