hokuu1102/Gowin2026-PolySynth/files/20-代码/ESP32侧工作计划-20260930.md

# 📋 ESP32 侧工作计划（⭐ 2026-09-30 制定）

> **制定人**：ESP32 线（本会话）
> **工作目录**：`C:\Users\hokuu\Desktop\FPGA\FPGA2026-esp32`（⚠️ **不是** `FPGA2026`）
> **当前 HEAD**：⭐ **以 `git log -1` 为准**（🔴🔴 **2026-09-30 更正**：⚠️ 原写 `c6112f9` + 「**4 个提交未推**」⇒ 🔴 **两者都已作废** —— ⭐ 未推数**以 `git status -sb` 的 `ahead N` 为准**，⛔ 本文不再写死）
> **板子状态**：⭐ **已烧入含 B 子集（`0xABF3` 命令）的固件**（🔴 原文写"跑的是 `86a1ed4`"⇒ **已过时**）
> **状态**：🔴🔴 **2026-09-30 更正 —— 本计划的 A / E / B 子集【均已完成】**（⚠️ 详见下方"执行结果"节）

---

## 〇、⭐⭐ 一句话

> ⭐ **按"是否被外部阻塞"分三类** ——
> ⭐ **能立刻做的只有 3 件**（A / E / F），
> 🔴 **B 被架构裁定阻塞**、⚠️ **C/D 价值中等**，
> 🔴 **其余全部依赖 FPGA 侧或物理接线。**

---

## 〇之二、✅✅ 执行结果（⭐ 2026-09-30 晚回填 —— ⚠️ 下文计划正文已按此读）

> 🔴🔴 **2026-09-30 更正**：⚠️ 本文原为**"待批准的计划"** ⇒ ⭐ **A / E / B 子集三项【均已落地并实测】**。
> ⚠️ 下文 §二 / §三 / §四 的"为什么 / 做什么"**仍有参考价值**（⭐ 保留），
> 🔴 **但其中的【状态】与【判据期望】已经实现** —— ⛔ **不要再当成待办做一遍**。

| 项 | 🔴 计划里写的 | ✅ 实际（2026-09-30） | ⭐ 证据 |
|---|---|---|---|
| **A** 上行缓冲 | 「🔴 计划新建 `up_ring.c/.h`」 | ✅ **已落地** —— `esp32/ble/main/up_ring.c/.h`，**160 KB in PSRAM** | ⭐ `u_in=2000`（🔴 原为 1611，丢 389） |
| **E** 一键验收 | 「⚠️ 计划新建 `e2e_accept.py`」 | ✅ **已落地** —— `esp32/tools/e2e_accept.py`（⭐ 通过退出码 0） | ⭐ 一条命令跑完 |
| **B** `0xABF3` 命令 | 「🔴 `0xABF3` 现在是**废的**」 | ✅ **已实现解析 —— 四个命令**：`0x01` 清池 · `0x02` 状态上报 · ⭐ **`0x03` 起播** · ⭐ **`0x04` 停止**<br>🔴🔴 **2026-10-01 更正**：⚠️ 本行原只写「`0x01` 清池 · `0x02` 状态上报」⇒ 🔴 **不完整**（⭐ 当晚又补了起播/停止） | ⭐ `esp32/ble/main/ble_main.c` 的 `case 0x01`/`0x02`/`0x03`/`0x04`（⭐ 截至提交 `35036bf` 在 `:606`/`:611`/`:629`/`:634`；⚠️ **行号会漂，⛔ 别写死**） |
| **C** `0xABF4` 上报 | 「⭐ `gatt_svc.c:157` 注册了**但从未被写**」 | ✅ **已可读** —— 🔴 原坏因是 `ESP_GATT_AUTO_RSP` + `length=0` ⇒ **读回空**；⭐ 改 `ESP_GATT_RSP_BY_APP`<br>🔴🔴 **2026-10-01 更正**：⚠️ 本行原写「⭐ 实测 `pool=0/18204 sent=0 ovf=0\|ring=0 u_drop=0/0`」⇒ 🔴 **那是旧的三组短格式，已作废**。⭐ 现值 = **八组**（`V1 mode=`/`pool=`/`ring=`/`ble=`/`uart=`/`hmi=`/`frame=`/`cmd=`，`cmd_report_status()` @ `ble_main.c:362`）<br>🔴🔴 **2026-10-01 修正：⚠️ 原文写「六组」且只列了 7 个名字（⭐ 漏了 `hmi=`）⇒ 实际格式串是【8 行】**（`ble_main.c:419-435`）；⭐ 且原引 `ble_main.c:336` ⇒ 【该行现在不是 `cmd_report_status`，函数已下移到 `:362`】<br>⭐ **`V1` 行带 `req=`/`up=`** ⇒ ⭐ **陈旧可判定**（提交 `35036bf`）<br>🔴 **且是【拉取快照】**：⭐ 只有先发 `CMD 0x02` 才刷新（⭐ 截至 `35036bf` 在 `:613`）<br>🔴🔴 **2026-10-01 修正：⚠️ 原文的"尺寸警告"（样本 261 B > `char buf[256]` @ `:352`）【已作废】** —— ⭐ 实测现值 `char buf[320]`（`ble_main.c:389`）＋ `s_val_stat[320]`（`gatt_svc.c:106`）⇒ ✅ **不再截断**（⭐ 原文写的是**扩容前**的状态）<br>⚠️ **字节数 ⛔ 别写死**：⭐ 工程里并存 **210 / 221 / 261 / 264** 四个互相矛盾的数（`gatt_svc.c:91`「约 210」· `今晚任务书-20260930.md`「约 221」· 本文「261」· `ESP32线交接文档-20261001.md`「264」）⇒ ⭐ 权威判据是 **`stat_read.py` 的"组齐全"检查**，⛔ 不是某个字节数 | ⭐ 实测六组见 `esp32/tools/stat_read.py` |
| **H** `esp32/bridge/` 波特率 | 「⚠️ 仍是 1 Mbps」 | ✅ **已同步 500 k** —— `BRIDGE_BAUD 500000` | ⭐ `esp32/bridge/main/bridge_config.h` |
| ⭐ **额外** 反向通路 | ⚠️ 计划**未列此项** | ✅ **已打通** —— ⭐ 2000 字节 round-trip 逐字节一致 | `esp32/evidence/反向通路验收-ESP32侧-20260930.md` |
| ⭐ **额外** 起播触发 | ⚠️ 计划**未列此项** | ✅ **已实现** —— UART1 RX（`GPIO18`）单字符 `S`/`X`/`R` | ⭐ `ble_main.c` `task_uart_to_ble` |
| 🔴 **按键脚** | ⚠️ 计划未提 | 🔴 **= `GPIO6`**（`BLE_BTN_GPIO 6`）—— ⛔ **不是 `GPIO0`** | `esp32/ble/main/ble_config.h` |

⚠️ **仍未做**：`uart_test` 诊断固件回归（⚠️ 需板）。
🔴🔴 **2026-10-01 修正：⚠️ 原文把「串口屏联调（🔴 屏未接）」列在【未做】里 ⇒ 【已作废】** —— ⭐ **屏已接上并全链路验收通过**（⭐ 屏上 6 栏全部跟着状态变；依据 `esp32/evidence/串口屏HMI验收报告-20261001.md`）。
⭐ **已完成（2026-10-01 补）**：`flash` 映像头 **2 MB → 16 MB**（`esp32/ble/sdkconfig.defaults:40-41` `CONFIG_ESPTOOLPY_FLASHSIZE_16MB=y` / `"16MB"`）
🔴🔴 **2026-10-01 更正**：⚠️ 本行原把「`flash` 映像头 2 MB→16 MB」列在**未做**里 ⇒ 🔴 **已作废**（⭐ 已落地，见 `files/20-代码/今晚任务书-20260930.md:75`）。

---

```
                    ┌─────────────────────────────┐
                    │  🔴 起播架构裁定（方案③vs模式B）│
                    └──────────────┬──────────────┘
                                   │ 阻塞
                                   ▼
                          🔴 B（CMD 口命令解析）

   ┌───────────────────────────────────────────────┐
   │  ⭐ 不依赖任何外部裁定 —— 可以立刻做            │
   │     · A（上行缓冲，⭐ 设计明说不依赖格式）      │
   │     · E（一键验收脚本）                        │
   │     · F（push）                                │
   └───────────────────────────────────────────────┘

                    ┌─────────────────────────────┐
                    │  ⚠️ 需要物理接线（只有用户能做） │
                    └──────────────┬──────────────┘
                                   │
                    ┌──────────────┴──────────────┐
                    ▼                             ▼
          ⚠️ 串口屏联调                   🔴 接 FPGA 联调
          （HMI 三件套）                  （⛔ 依赖 uart_tx.v）
```

---

## 二、⭐ 立刻能做（⛔ 不依赖任何人）

### ⭐ A —— 实现上行缓冲（⭐ 推荐第一件）

| 项 | ⭐ 内容 |
|---|---|
| **为什么** | 🔴 **唯一有"静默丢数据"风险的缺口** —— ⭐ 实测 **2000 → 1611**(丢 389,⚠️ **无任何报错**) |
| **做什么** | ⭐ 按 `files/20-代码/上行通路缓冲设计-20260930.md`（⭐ 745 行,已评审）实现：<br>· 新建 `up_ring.c/.h`(⭐ **PSRAM 优先**,⭐ 复用 `pool_alloc` 的降级模式)<br>· **32 KB**(⭐ 655 ms 线速突发 / 52.4 s 音乐节拍余量)<br>· ⭐ **保持单任务**(🔴 硬约束:同一个 UART 只能有一个读者)<br>· ⭐ **丢最旧** + ⭐ **8 个可观测字段** |
| ⭐ **关键收益** | ⭐ **把"静默丢失"变成"带账丢失"** —— ⭐ 这是它胜过"调大驱动缓冲"的**核心理由** |
| ⛔ **不依赖** | ⭐ **不依赖上行格式**(⭐ 纯字节流)⇒ ✅ **可以在格式定下来之前就做** |
| ⚠️ **代价** | ⚠️ 新增模块 + 改 `ble_main.c` + **重烧**；⚠️ 需实测验收 |
| ⭐ **判据** | ①灌 2000 字节 ⇒ **`u_in` 必须 = 2000**(⭐ 反向判据:若仍 1611 说明没生效)<br>②持续超发 ⇒ **`u_drop` 必须增长**(⛔ 不是静默丢)<br>③⭐ **非空洞性**:`u_hwm` ≤ 2000(⭐ 证明环真被用上) |
| ⚠️ **不解决** | 🔴 **持续过载仍会丢**(⭐ 缓冲只吸收突发)⇒ ⚠️ **根治仍需 FPGA 侧按节拍发** |

### ⭐ E —— 一键端到端验收脚本

| 项 | ⭐ 内容 |
|---|---|
| **为什么** | ⚠️ 现在验收要**手动串 3 步**(清池 → 灌数据 → 触发+抓包),⭐ 每次联调都重复 |
| **做什么** | ⭐ 一个脚本串起来:清池 → BLE 灌 N 帧 → 起播 → 抓 `GPIO17` → **打印判据对账表** |
| ⭐ **收益** | ⭐ **下一次联调省事**;⭐ 且把判据**固化**(⛔ 不靠人记) |
| ⚠️ **代价** | ⚠️ 低(⭐ 只是把已有工具串起来) |
| ⭐ **判据** | ⭐ 一条命令跑完,输出 `total/tf/rst/unk/ovf/mismatch/clamp/rate` 全绿 |

### ⭐ F —— push 未推的 4 个提交

| 项 | ⭐ 内容 |
|---|---|
| **为什么** | ⚠️ 4 个提交压在本地(`0edae6e` / `46fb1b5` / `690d644` / `c6112f9`) —— 🔴🔴 **2026-10-01 修正：⚠️ 该数字与 SHA 均为 2026-09-30 快照，【已过时】**；⭐ **未推数一律以 `git status -sb` 的 `ahead N` 为准，⛔ 不写死**（⭐ 本文开头 `:5` 已立此规矩） |
| **做什么** | ⭐ 按纪律**压成 1 个**再推(⭐ 备份 tag + bundle) |
| ⚠️ **前提** | 🔴 **需要你点头** |
| ⭐ **内容** | `gatts_if` 修复 + 延时陷阱 + 压力测试发现 + 两份文档 |

---

## 三、⚠️ 被阻塞的（🔴 需要先裁定）

### 🔴 B —— `0xABF3`(CMD) 命令解析

| 项 | ⭐ 内容 |
|---|---|
| **为什么重要** | 🔴 **CMD 口【原文写"现在是【废的】"】—— 🔴🔴 2026-09-30 更正：⚠️ 该断言已作废** ✅<br>⭐ **原文**：「`ble_main.c:367` 把 `0xABF3` 与 `0xABF1` **走同一段代码**,⚠️ 写进去会被当**曲谱数据**吃掉」<br>✅ **现状**：⭐ **已剥离分支并实现命令解析**（`0x01` 清池 · `0x02` 状态上报）⇒ ⛔ **写 `0xABF3` 不再被当曲谱数据** |
| 🔴 **为什么被阻塞** | ⭐ **命令语义 = 起播归属问题** —— ⚠️ 而「方案③ vs 模式B」**尚未裁定**<br>⭐ 裁定单 `:161` 已把改法写清(剥离分支 + 加解析 + 判 `pool_frames()>0`),⚠️ **但前提是裁定结果** |
| ⚠️ **能绕过吗** | ⚠️ **部分能** —— ⭐ 可以先定一个**与架构无关的子集**(如 `0x03` = 读状态、`0x04` = 清池),⚠️ **但"起播"那条必须等裁定** |
| ⭐ **建议** | ⚠️ **先只做"清池"和"读状态"两个无争议命令**,⛔ **把"起播"留到裁定后** |

---

## 四、⚠️ 价值中等 / 可延后

| # | 事项 | ⭐ 说明 | ⚠️ 建议 |
|---|---|---|---|
| **C** | ✅ **`0xABF4`(STAT) 上报状态 —— 【已完成】** | 🔴🔴 **2026-09-30 更正**：⚠️ 原文写「⭐ 已注册(`gatt_svc.c:157`)但**从未被写**」⇒ 🔴 **已作废**。⭐ **现值可读** —— 🔴 **原坏因**：属性用 `ESP_GATT_AUTO_RSP` 且 `length=0` ⇒ **读回空**；⭐ **已改 `ESP_GATT_RSP_BY_APP`**。<br>🔴🔴 **2026-10-01 再更正**：⚠️ 本行原写「⭐ 实测返回 `pool=0/18204 sent=0 ovf=0\|ring=0 u_drop=0/0`」⇒ 🔴 **旧的三组短格式，已作废**。⭐ 现值 = **八组**（`cmd_report_status()` @ `ble_main.c:362`；缓冲区 **320 B**，`gatt_svc.c:106` `s_val_stat[320]`）<br>⭐ **`V1` 行带 `req=`（快照序号）/ `up=`（生成时刻）** ⇒ ⭐ **陈旧【可判定】**（提交 `35036bf`）<br>🔴 **但它仍是【拉取快照】**：⭐ **只有先发 `CMD 0x02` 才刷新**（⭐ 截至 `35036bf` 在 `:613`）⇒ ⚠️ 不发就直读 = 旧内容（⭐ 能判定，⚠️ 不自动刷新）<br>🔴🔴 **2026-10-01 修正：⚠️ 原文的"尺寸警告"（261 B > `char buf[256]` @ `:352`）【已作废】** —— ⭐ 实测 `char buf[320]`（`ble_main.c:389`）＋ `s_val_stat[320]`（`gatt_svc.c:106`）⇒ ✅ **不再截断**（⭐ 原文是**扩容前**的状态）<br>⚠️ **字节数 ⛔ 别写死**（⭐ 210/221/261/264 四个数在工程里并存） | ✅ **已完成**（⭐ 与 `0x02` 配套；⭐ 读工具 = `esp32/tools/stat_read.py`） |
| **D** | ✅ **`send_frames_ble.py` 支持收 notify —— 【已完成】** | ⚠️ 原文写「现在只能发不能收」⇒ 🔴 **已作废**：⭐ 已支持**订阅 `0xABF2` + 统计通知条数/字节数**（`send_frames_ble.py:240-244/275-277`） | ✅ **已完成**（⭐ 并入 E） |
| **G** | **`uart_test` 清插桩后回归** | ⚠️ 确认诊断固件仍可用（⭐ 仍待做 —— ⚠️ 需板） | ⚠️ **仍待做** |
| **H** | ✅ **`esp32/bridge/`(SPP) 也改 500k —— 【已完成】** | 🔴🔴 **2026-09-30 更正**：⚠️ 原文写「⚠️ 仍是 1 Mbps」⇒ 🔴 **已作废**：⭐ `BRIDGE_BAUD 500000`（`esp32/bridge/main/bridge_config.h`） | ✅ **已完成**（⭐ 三个宏全 `500000`） |
| **I** | ✅ **`flash` 2 MB → 16 MB 映像头 —— 【已完成】** | 🔴🔴 **2026-10-01 更正**：⚠️ 原文写「`flash` 2 MB 映像头上限 · ⚠️ 实为 16 MB,⚠️ 不阻塞」⇒ 🔴 **该待办已关闭**。⭐ 现值 = **16 MB**（`esp32/ble/sdkconfig.defaults:40-41` `CONFIG_ESPTOOLPY_FLASHSIZE_16MB=y` / `"16MB"`；⭐ 落地记录 `files/20-代码/今晚任务书-20260930.md:75`，⭐ 分区表未动） | ✅ **已完成** |
| **J** | 屏的三份文档 ↔ 固件**一致性复核** | ✅🔴🔴 **2026-10-01 修正：⚠️ 原文写「⭐ HMI 从未真机验证 ⇒ ⚠️ 可能已脱节」⇒ 【已作废】** —— ⭐ **屏已于 2026-10-01 真机验收通过**（`esp32/evidence/串口屏HMI验收报告-20261001.md`）⇒ ⚠️ **本条现在【可执行】**：拿屏上实际控件名/属性名 ↔ `hmi.c` 对照 | ⚠️ 中(⭐ 现在就能核) |

---

## 五、🔴 我做不了的（⛔ 边界，⭐ 必须你或 FPGA 侧做）

| # | 事项 | ⭐ 谁 | ⚠️ 为什么卡 |
|---|---|---|---|
| **1** | 🔴 **接 FPGA 联调** | ⭐ **你** | ⚠️ 物理接线;⚠️ **FPGA 侧的上行发送模块（`uart_tx.v`）是否就位以 `rtl/` 为准** ⇒ ⭐ **本节原文写"`uart_tx.v` 不存在 ⇒ 上行根本收不到东西"—— 🔴🔴 2026-09-30 更正：⚠️ 该断言【对 ESP32 侧已不成立】**<br>✅ ⭐ **ESP32 侧的收→转发链路已实测可用**：写 `GPIO18` 的 **2000 字节 ⇒ BLE `0xABF2` 原样出来、逐字节一致**（`esp32/evidence/反向通路验收-ESP32侧-20260930.md`） |
| **2** | 🔴 **接串口屏 + 5V 供电** | ✅ **已完成（2026-10-01）** | 🔴🔴 **2026-10-01 修正：⚠️ 原文写「屏至今未接 ⇒ HMI 397 行代码从未跑过」⇒ 【已作废】** —— ⭐ **屏已接 + 5V 供电，HMI 全链路已真机验收**（⭐ `GPIO4`(TX)→屏 `RX` · `GPIO5`(RX)←屏 `TX` · 5V · GND；依据 `esp32/evidence/串口屏HMI验收报告-20261001.md`） |
| **3** | 🔴 **起播架构裁定** | ⭐ **你 + FPGA 侧** | ⭐ 阻塞 B |
| **4** | 🔴 **上行格式定义** | ⭐ **FPGA 侧** | ⚠️ **一个字节都没定** |
| **5** | ⚠️ **`§4.4 不做反向通道` ⇔ 要回传事件** | ⭐ **双方** | ⚠️ 矛盾已摆出,⏳ 待裁定 |

---

## 六、⭐⭐ 建议的执行顺序

| 序 | 事项 | ⭐ 理由 | ⚠️ 风险 |
|---|---|---|---|
| **1** | ⭐ **A（上行缓冲）** | 🔴 **唯一有静默丢数据风险的缺口**;⭐ 且**不依赖任何裁定** | ⚠️ 中 |
| **2** | ⭐ **E（一键验收）** | ⭐ 让 A 的验收**可重复**;⭐ 也为将来联调铺路 | ⚠️ 低 |
| **3** | ⭐ **F（push）** | ⚠️ 需你点头 | ⚠️ 低 |
| **4** | ⚠️ **B 的子集**（清池/读状态） | ⭐ 补 `0xABF3` 的口,⚠️ 但**绕开"起播"** | ⚠️ 中 |
| **5** | ⚠️ **等你接线** ⇒ 屏 / FPGA 联调 | ⭐ **那才是真正的验收** | — |

---

## 七、⚠️ 本计划的边界

| # | 说明 |
|---|---|
| **1** | 🔴🔴 **【2026-09-30 已执行完毕，⛔ 勿重做】** —— ⚠️ 原文为"本计划不含任何代码改动 —— ⭐ 待批准" |
| **2** | ⚠️ **A 做完也必须重烧** ⇒ ⚠️ **板子当前固件会变**(⭐ 现在跑的是已推送的 `86a1ed4`) |
| **3** | 🔴 **A 不能替代 FPGA 侧限速** —— ⭐ **两者互补**(⭐ 缓冲吸收突发,节流根治持续过载) |
| **4** | ⚠️ **B 的"起播"部分⛔ 不做** —— ⚠️ 等裁定 |
| **5** | ⭐ **屏与 FPGA 的联调⛔ 不在本计划内** —— ⚠️ 需要你接线 |

---

## 附 · 证据索引

**实测**
`esp32/evidence/放水时序验收报告-20260930.md`（⭐ 放水打通,`rate=1919`）·
`esp32/evidence/反向通路验收-ESP32侧-20260930.md`（⭐ 21 字节通 + **丢字节限制**）·
`esp32/evidence/205帧BLE验收报告-20260930.md` · `esp32/evidence/UART验收报告-20260930.md`

**设计 / 裁定单**
`files/20-代码/上行通路缓冲设计-20260930.md`（⭐ A 的依据,745 行）·
`files/20-代码/反向通路对接单-给FPGA侧-20260930.md`（⭐ 含 Q1~Q5）·
`files/20-代码/矛盾裁定单-方案3与模式B-20260930.md`（⭐ 阻塞 B）

**代码位置（⭐ 本计划引用的）**
> 🔴🔴 **2026-10-01 修正：⚠️ 下面三条【全部已作废】—— 断言的"缺陷"都已修掉，行号也都不对了。**
> ⛔ **不要照它们去查代码**；⭐ 一律按【符号名】定位。

~~`esp32/ble/main/ble_main.c:367`（🔴 CMD 与 RECV 同路径）~~ ⇒ ✅ **已修**：⭐ CMD 口**已剥离独立解析**（`if (h == s_handle_cmd)` @ `ble_main.c:655`；⭐ `case 0x01`/`0x02`/`0x03`/`0x04`/`0x20`/`0x21`/`0x22` @ `:659`/`673`/`691`/`696`/`712`/`724`/`753`）·
~~`esp32/ble/main/gatt_svc.c:157`（⚠️ STAT 已注册未使用）~~ ⇒ ✅ **已修**：⭐ STAT **已可读**（`ESP_GATT_RSP_BY_APP` @ `gatt_svc.c:180` 起的修复块；⭐ 缓冲区 `s_val_stat[320]` @ `:106`）·
~~`esp32/ble/main/ble_config.h:117`（⚠️ RX 缓冲 1026 B）~~ ⇒ ✅ **已改**：⭐ 实测现值 `#define BLE_UART_RX_BUF (8 * 1024)` @ **`ble_config.h:143`**（⭐ `:117` 现在是那段扩容说明的注释起点）
