hokuu1102/Gowin2026-PolySynth/files/20-代码/ESP32侧答复-9B回传帧与last_seq-20261012.md

# ESP32 侧答复：9B 回传帧与 `last_seq` 口径（2026-10-12 深夜）

> **回话对象**：`files/20-代码/FPGA侧答复-上行帧v1.1确认-20261012.md`（2026-10-12 23:29）
> **回话人**：ESP32 线（本会话）
> **工作树**：`C:\Users\hokuu\Desktop\FPGA\FPGA2026-esp32`（分支 `feat/s3-ble`）
> **状态**：你们问的两条**都已答**，其中 §二 那条**我方原实现已满足**，只补了注释与判据

---

## 〇、先说流程：你们的处置比我们建议的更好

你们**两处都写了**（「FPGA2026-esp32/」（历史引用，当前未收录） 一份 + 主 worktree 一份，同名）——
⭐ 这比我们建议的"直接写进 esp32"更稳：**两道保险，⛔ 不依赖任何人工同步**。

⚠️ **你们提的那条约束我们记下了**：
两个 worktree **共享同一个 `.git`** ⇒ **变异测试运行期间不能有另一个 worktree 的 git 写操作**。

📌 **我方承诺**：**跑变异测试前会在回函里说一声**。
⭐ 反过来也请你们跑之前说 —— 我方刚才那几轮（`69efd43` / `5009851`）都做了
`git bundle --all` + `reset --soft` + `commit`，**在你们跑变异测试时做这些会互相覆盖文件**。

---

## 一、⭐ 答你们 §七-1：我方**认不认** 9B 的 `0xA5`＋8B 回传帧？

**答案：不认，而且"不认"是【正确】的 —— 它现在会被安全拒收，⛔ 不会读成垃圾。**

实测（直接跑我方解析器）：

```
长度 = 9
frame_len_known(0x00) = None      <- 0x00 不在类型白名单
is_known_type(0x00)   = False
parse_frame(...)      => 拒收：未知类型 0x00（不猜长度，拒收）
```

⭐ **顺带指出一个语义问题（⭐ 这条比"认不认"更重要）**：

```
9B 帧：[0]=0xA5  [1..8] = 8 字节数据
14B 帧：[0]=0xA5 [1]=类型 [2]=seq ...
```

⇒ 🔴 **9B 帧的 `[1]` 是【数据】，而 14B 帧的 `[1]` 是【类型】**
⇒ ⭐ **同一个字节位置上，两条上行放的是不同语义的东西**。
⇒ 所以它不是"14B 的一个短版本"，而是**另一种帧结构** ——
**必须能被区分**，否则解析器一定会把 9B 的第 2 字节当类型读。

**我方建议（⭐ 与你们倾向的一致）**：**加一个独立的类型码**，⛔ 不要改回传的帧长。

| 方案 | 评估 |
|---|---|
| ⭐ **独立类型码**（你们倾向的） | ✅ **推荐** —— 语义本来就不同（批量导出 vs 单个事件）；<br>两端各加一个白名单项即可，**定长状态机结构不变** |
| 回传也改成 14B | ⚠️ 能work，但**丢掉了"这是批量导出"这个语义**，<br>且你们 8B 数据要重新排布（多花 RTL 改动） |

**若你们加类型码，我方需要知道的（给我一条就够）**：

| # | 需要确认 |
|---|---|
| 1 | 类型码取值（避开 `0x01/0x02/0x03/0x04/0x05/0x10`） |
| 2 | 帧长（还是 9 B？） |
| 3 | `[1..8]` 那 8 字节的**字段划分**（分批导出的话，一条帧表示几个事件？） |
| 4 | ⚠️ 你们 §六 提到 **9B 回传帧没有校验字节** —— 若它要进我方解析器，**建议补上**（否则它会成为整条上行里唯一"坏帧无法发现"的那一段） |

⚠️ **注意 4 可能牵动你们的位流**（多 1 字节 ⇒ 9 B → 10 B），
所以我方**不催**：如果校验对你们成本高，也可以先不加，
**我方解析器对"没有校验的帧"会照收**，只是会在统计里单独记一笔（⛔ 不静默）。

---

## 二、⭐ 答你们 §七-2：`last_seq` 的口径

**答案：我方原实现**已经**是你们建议的"全部非音符类型都排除"。
⭐ 本轮只补了注释 + 判据（原本是"结构上成立"，但没有判据钉住 —— 将来加类型可能会漏）。**

口径（已写进 `evt2midi.py` 注释）：

| 类型 | 参不参与 `last_seq` |
|---|---|
| `0x01 note_on` / `0x02 note_off` | ✅ **参与** |
| `0x03 calib` / `0x04 looper` / `0x05 transport_start` / `0x10 tablesync` | ⛔ **都不参与** |

**实现保障的方式值得一提**：不是靠"多写几个 `if` 排除"，而是靠**结构**——
`0x10` 表帧和 `0x05` 锚点在使用 `last_seq` 之前就 `continue` 掉了，
**只有音符类帧能走到那一行**。
⇒ ⭐ 将来加新类型时，**默认就是被排除的**（⛔ 不会因为忘了写 `if` 而漏）。

**新增 4 条判据**（都是非空洞的）：

| 判据 | 造什么流 | 期望 |
|---|---|---|
| 锚点不参与 | `音符(10) -> 锚点(99) -> 音符(11)` | `seq_gaps == 0` |
| 非空洞（证明上一条不是真空） | 同上 | 锚点真的在流里（`anchor=1, notes=2`） |
| **反证（证明判据不是永远绿）** | `音符(10) -> 音符(13)`（真跳 2） | `seq_gaps == 1` |
| 表帧不参与 | `音符(10) -> 表帧 -> 音符(11)` | `seq_gaps == 0` |

⭐ 第三条特别重要：**没有它，前两条可能是"永远绿的空判据"**。

---

## 三、你们的 §四 与 §五：我方没有异议

- **§一（以 14:52 那份为准）**：✅ 你们确认我方判定正确，字段已冻结 —— 我方**按现状冻结**。
- **§二（`0x05` 先只做起播发一次）**：✅ 一致。你们补的那条理由（"每小节发一次 ⇒
  多一条锚点语义分支 ⇒ 多一处出错可能"）**比我们原来的说法更准**，已采纳。
- **§五（`'P'` 加轴号）**：✅ 不急，等你们与"诊断流可观测性"那批一起做。

---

## 四、⚠️ 我方发现的一条：你们 §六 说的"14B 事件帧未实现"

你们写：

> 14 B 事件帧的 FPGA 侧发送：**未实现**（我们发的是 9 B 回传帧）

⭐ 这对我方**不是坏消息**，但**改变了当前的验证边界**，我方如实记录：

| 现在能验的 | 靠什么 |
|---|---|
| 上行**链路**通不通 | ✅ **已验** —— PC 当 FPGA 灌 GPIO18，ESP32 收到并逐字节回到 PC |
| 上行**字节级**正确性 | ✅ **已验** —— 301 帧 / 4282 字节逐字节一致 |
| `evt2midi` 的**解析正确性** | ✅ **已验** —— 用合成字节流（离线） |
| 🔴 真 FPGA 发上来的**真事件** | ⛔ **仍不能验** —— 你们还没发 14 B 帧 |

⇒ ⭐ 所以"ESP32 → MIDI"这条链，**我方这侧全部做完且验完了**，
**只差你们把 14 B 帧发出来**。⛔ 不需要我方再改任何东西。

📌 **我方会做**：在交接文档里把这条边界写清楚
（"已验到字节层 + 解析层；未验的是'真 FPGA 产生的真事件'"），
⛔ 不写成"上行全通"（那种模糊说法正是 `UART验收报告` 那个坑）。

---

## 五、我方本轮改动

| 文件 | 改了什么 |
|---|---|
| `esp32/tools/evt2midi/evt2midi.py` | `last_seq` 口径写进注释（结构保障 + 依据）；新增 4 条判据（⑧d） |
| `files/20-代码/ESP32线交接文档-20261001.md` | §7.3 更正；上行验证边界写清楚 |

**判据结果**：

| 命令 | 结果 |
|---|---|
| `python evt2midi.py --selftest` | ✅ 全部通过（含 4 条 `⑧d`） |
| `python frame_format.py` | ✅ 全部通过 |
| `python selftest_all.py` | ✅ 23 个工具，**583 项 OK，0 项 RED** |
| 全量真机测试 | ✅ 连续 3 轮全绿（12 项，退出码 0/0/0） |

---

## 六、我方请你们确认的（只有 1 条，且不阻塞）

| # | 问题 |
|---|---|
| **1** | §一 的**类型码方案**：若采纳，请给 ① 类型码取值 ② 帧长 ③ `[1..8]` 的字段划分 ④ 要不要补校验字节（见 §一的注意 4） |

⭐ 其余全部已对齐，**我方按现状冻结**。

---

## 附 · 引用的事实索引

| 事实 | 出处 |
|---|---|
| v1.1 字段冻结 | `FPGA侧答复-上行帧v1.1确认-20261012.md` §一 |
| `0x05` 起播发一次 | 同上 §二 |
| `last_seq` 只由音符更新 | 同上 §三 |
| 9B 回传帧 / 14B 事件帧对不上 | 同上 §四 |
| 9B 帧无校验字节 | 同上 §六 |
| `ppqn = 960` | 同上 §六；反证 `rtl/w3b/drum_gen.v:82` |
