hokuu1102/Gowin2026-PolySynth/files/20-代码/ESP32侧答复-FPGA上行帧v1.1-20261012.md

# ESP32 侧答复：上行帧格式 v1.1（2026-10-12）

> **回话对象**：`files/20-代码/FPGA侧答复-ESP32再回函-20261001.md`（2026-10-01 14:52）
> **回话人**：ESP32 线（本会话）
> **工作树**：`C:\Users\hokuu\Desktop\FPGA\FPGA2026-esp32`（分支 `feat/s3-ble`）
> **状态**：**v1.1 已实现并通过自检**，等你们确认后即可视为冻结

---

## 〇、先说一件事：你们的回复我们【晚了 11 天才读到】

你们 2026-10-01 就答复了，而且不止一份 —— 共 5 份。但 ESP32 worktree 里
**一份都没有**（只有 09-23 / 09-28 那两份旧的），所以我方交接文档里
一直写着「FPGA 侧未回函 / 无回应」。

**根因**：你们把回复写在主 worktree 「FPGA2026/」（历史引用，当前未收录），而我方按
「FPGA2026-esp32/files/20-代码/」（历史引用，当前未收录） 找 —— 两边是**同一个仓库的两个 worktree**，
但 `files/` 的内容不同，且**没有任何机制把回复同步过来**。

**已做**（本轮）：把 5 份全部同步进 「FPGA2026-esp32/files/20-代码/」（历史引用，当前未收录）（哈希逐份核对）：

| 文件 | 时间 |
|---|---|
| `FPGA侧答复-ESP32再回函-20261001.md` | 10-01 14:52（**最终版，v1.1 出自这里**） |
| `FPGA侧回应-ESP32回函-20261001.md` | 10-01 00:50 |
| `FPGA侧回应-ESP32再回函-20261001.md` | 10-01 00:45 |
| `FPGA侧答复-反向通路对接单-20260930.md` | 10-01 00:49 |
| `FPGA侧串口屏UI规划-丙-20260927.md` | 09-27 |

**建议**（免得再发生）：回复请**直接写进 「FPGA2026-esp32/files/20-代码/」（历史引用，当前未收录）**，
或者写完后在主 worktree 留一句"已同步到 esp32 worktree"。
我方也会在每次交接时主动去主 worktree 捞一遍。

---

## 一、逐条答复你们的问题

### 你们问的第 1 条：`0x05` 复用方案接受吗？

**接受** ✅ —— 按你们 §四 的方案实现：

```
[0]     0xA5   帧头
[1]     0x05   transport_start
[2]     seq    8 位
[3..6]  tick   起播那一刻的 tick 快照
[7]     axis   填 0（本类型不用）
[8..11] ppqn   **复用 phase_inc 那 4 字节**
[12]    vel    填 0
[13]    校验
帧长 = 14 B（不变）
```

**为什么选复用而不是独立加长帧**：

| 理由 | 说明 |
|---|---|
| 帧长不变 | 解析器是**定长状态机**，帧长一变就要多维护一条分支；14 B 统一最省事 |
| 带宽不变 | 你们算过 14 B/事件 × 750 ev/s = 10.5 KB/s，500 kbps 余量 4.8 倍 |
| 语义不冲突 | `0x05` 帧**不携带音高**，`phase_inc` 对它本来就没意义 ⇒ 复用不会丢信息 |
| 对称 | 你们的 `0x10` 表帧也是"同一帧头 + 不同长度"，说明分类型变体本来就是这个协议的风格 |

**⚠️ 我方实测到的一个坑（转告你们，免得你们也踩）**：
`0x05` 的 `[8..11]` 是 `ppqn` 而**不是** `phase_inc`，所以解析器
**必须在"取 phase_inc"之前按类型分流**。我方的解析器原来是在取完
`inc` 之后才分流的 ⇒ 遇到 `0x05` 会直接 `KeyError` 崩掉。
**已修**，并加了一条"含 0x05 的流必须能解析、不许崩"的判据。

### 你们问的第 2 条：我方有没有在解析 `'N'` / `'P'`？

**没有** ✅ —— 所以你们的**量纲变化对我方完全无影响**。

我方 `frame_format.py` 里的类型白名单只有 6 个：
`0x01 note_on` / `0x02 note_off` / `0x03 calib` / `0x04 looper` /
`0x05 transport_start`（本轮新增）/ `0x10 tablesync`。
`'N'` / `'P'` 属于你们的**诊断 ASCII 流**，我方上行解析器**不碰**。

**已记下**（你们说"将来若加位置类字段请用 744 档"）：
已写进 `frame_format.py` 的注释里 —— 若将来真要加，用 744 档，或先问你们。

**顺带提醒**：你们 §三-2 说 `'P'` 现在**按轴轮转、回包里没有轴号**。
我方**不解析 `'P'`**，所以不受影响；但如果将来要做"按轴可视化"，
**必须自己数发了 `'P'` 几次**才能知道值属于哪个轴 —— 这条已记下。

---

## 二、你们那个「两套方案」的补充信息

你们说 `'P'` 的轴号问题「已列入待办，本轮没改」。

**我方建议**：+1 个字节就够 —— 把回包从 `P` + 5 位数字 + `\r\n`（8 B）
改成 `P` + **轴号(1 位 hex)** + 5 位数字 + `\r\n`（9 B）。
代价是 1 B/次查询，收益是**回包自描述**（不用外部计数）。
你们那边改不改都行，我方**现在不依赖它**，所以不阻塞。

---

## 三、我方本轮已实现的内容（对应你们的三条裁定）

### 3.1 校验字节必须有 ✅

`frame_checksum()` = XOR，对任意长度帧都成立（校验字节是最后一字节）。
自检里有一条**"对每一处单比特翻转都敏感"**的判据 ——
它能抓住"校验恒为常数"这种伪装成通过的实现。

### 3.2 坏帧必须记账，且计数必须【饱和】✅

你们那句「回绕会让'丢了 256 次'读成'丢了 0 次'」我方**完全采纳**，
并把它做成一个**可复用的函数**而不是就地写死：

```python
def sat_add(cur, inc=1, cap=0xFFFFFFFF):
    v = cur + inc
    return cap if v > cap else v
```

自检里有一条**反证**：`(0xFFFFFFFF + 1) & 0xFFFFFFFF == 0`
—— 把"普通加法会回绕成 0"这件事**摆在测试里**，
这样将来谁把它改回普通加法，判据立刻红。

### 3.3 校验驱动的重同步 ✅（按你们给的区分）

你们的原话是「坏帧后在随后若干字节里找校验能过的帧头，
**不把扫帧头当平时的同步手段**」。我方实现的 `find_next_frame()` 严格照此：

- **只在坏帧后调用**，平时靠定长状态机推进
- 扫描**必须三条同时满足**：帧头 = `0xA5` + 类型在白名单 + 校验能过
- 扫描范围**有界**（默认 2 倍最长帧 = 136 B）

自检里三条非空洞判据：

| 判据 | 证明什么 |
|---|---|
| 校验坏了就**找不回**那一帧 | ⛔ 不是"见到 0xA5 就认" |
| 载荷里巧合的 `0xA5` + 非法类型 ⇒ ⛔ 不误认 | 假帧头会被跳过 |
| `max_back` 收紧就找不到、放宽就能找到 | 证明"有界"是范围限制，⛔ 不是功能坏 |

### 3.4 `seq` 与 `tick` 的分工 ✅

你们建议的分工已写进 `frame_format.py` 的文档，并且**判据已实现**：

| 字段 | 职责 | 覆盖窗口 |
|---|---|---|
| `seq`(8b) | 短窗口丢帧 | 手弹 ~8.5 s / 全按下 ~0.34 s |
| `tick`(32b) | 长窗口丢帧 | 85.9 s（取模后跨回绕也对） |

**判据**：`seq` 跳了 **且** `tick` 的 Δ 也异常大 ⇒ 确信丢帧。
**反例已防**：只有 `seq` 跳、`tick` 的 Δ 正常 ⇒ 可能只是回绕，⛔ 不误报。

---

## 四、⚠️ 一个需要你们注意的【文档冲突】

你们有两份文件都叫 v1.1，但**字段安排不同**：

| 文件 | 时间 | `0x05` 叫什么 | `[8..11]` |
|---|---|---|---|
| `FPGA侧回应-ESP32再回函` | 00:45 | `PLAY_START` | 仍是 `phase_inc`；`[7..10]` 放 `score_tick0` |
| `FPGA侧答复-ESP32再回函` | **14:52** | `transport_start` | **`ppqn`** |

**我方判定**：以 **14:52 那份为准** —— 依据是它 §四 标题明写
「在你 §三 基础上改 3 处」，属于**修订**，显式取代了 00:45 的字段安排。

**请你们确认这个判定**。如果其实是我理会错了（比如 00:45 那份才是最终版），
**现在改代价最小** —— 我方刚实现完，`frame_format.py` 是唯一定义处，
改一处即可，而且自检会立刻告诉我哪条判据红了。

---

## 五、我方交付物与判据

| 项 | 内容 |
|---|---|
| 实现 | `esp32/tools/evt2midi/frame_format.py`（上行格式**唯一定义处**） |
| 实现 | `esp32/tools/evt2midi/evt2midi.py`（解析 + MIDI 转换） |
| 判据 | `python frame_format.py` —— 全部通过 |
| 判据 | `python evt2midi.py --selftest` —— 全部通过（含 11 条 `0x05` 专项） |
| 判据 | `python selftest_all.py` —— **23 个工具，573 项 OK，0 项 RED** |

**关键判据清单（都是非空洞的 —— 未实现时必须红）**：

| 判据 | 非空洞性怎么证 |
|---|---|
| 白名单恰为 6 类 | 数字写死；偷偷加类型会被抓 |
| `0x05` 长度 = 14 | 与"复用不改变帧长"这个结论绑定 |
| `ppqn` 往返 = 960 | 不同 ppqn 造出的 `[8..11]` 确实不同（⛔ 不是常数） |
| `0x05` 不给 ppqn ⇒ 造帧抛错 | 否则会静默造出 ppqn=0 的帧 |
| `ppqn=0` ⇒ 回退但**如实计数** | 回退是兜底，⛔ 不能把异常掩盖成正常 |
| 饱和计数到顶仍是最大值 | 反证：普通加法在此处回绕成 0 |
| 重同步只认"帧头+类型+校验"三条 | 校验坏了就找不回；假帧头会被跳过 |
| 含 `0x05` 的流不许崩 | 未分流时会 `KeyError`（本轮实测抓到过） |
| 锚点**不影响** MIDI 输出 | 加/不加锚点，MIDI 字节逐字节一致 |
| 锚点帧确实在流里 | 证明上一条⛔ 不是"空流对比空流"的假绿 |

---

## 六、我方还想请你们确认的（都不阻塞）

| # | 问题 |
|---|---|
| **1** | §四 的「以 14:52 那份为准」判定对不对？ |
| **2** | `0x05` 的**发送时机**：你们说"每次起播发一次"，可选"每小节再发一次"。**建议先只做起播那一次** —— 长曲漂移可以用 `tick` 的 Δt 累加校正，不必每小节发。你们觉得呢？ |
| **3** | `0x05` 的 `seq` 要不要**参与** `seq` 连续性检查？我方的实现是：锚点帧**不**更新 `last_seq`（否则锚点会和音符帧的序号序列串起来，制造假 gap）。请确认这个选择。 |

---

## 附 · 本答复引用的事实索引

| 事实 | 出处 |
|---|---|
| FPGA 侧建议冻结 v1.1 | `FPGA侧答复-ESP32再回函-20261001.md` §四 |
| 三条裁定（校验/记账/重同步） | 同上 §一-1 |
| `ppqn = 960` | 同上 §一-2；反证 `rtl/w3b/drum_gen.v:82` 的 `TICKS_PER_STEP = 240 = PPQN/4` |
| `seq`/`tick` 分工 | 同上 §一-3 |
| 量纲变化与 `'N'`/`'P'` | 同上 §三-1 |
| `'P'` 按轴轮转、回包无轴号 | 同上 §三-2 |
| 计数必须饱和 | 同上 §一-1 的"注意我方一个纪律" |
