hokuu1102/Gowin2026-PolySynth/files/20-代码/ESP32侧详细执行计划-20260930.md

# 🔨 ESP32 侧 —— 详细执行计划（⭐ 按顺序完成，2026-09-30）

> **制定人**：ESP32 线（本会话）
> **工作目录**：`C:\Users\hokuu\Desktop\FPGA\FPGA2026-esp32`（⚠️ **不是** `FPGA2026`）
> **依据**：`files/20-代码/ESP32侧工作计划-20260930.md`（⭐ 分类版）
> **本文件**：⭐ **详细到"每一步做什么、判据是什么、失败了查哪"** —— ⚠️ 仍⛔ **不含代码改动**
> **当前 HEAD**：⭐ **以 `git log -1` 为准**（🔴🔴 **2026-09-30 更正**：⚠️ 原写 `d4bb533` + 「🔴 **5 个提交未推**」⇒ 🔴 **两者都已作废** —— ⭐ 未推数**以 `git status -sb` 为准**）

---

## 〇之二、✅✅ 执行结果（⭐ 2026-09-30 晚回填）

> 🔴🔴 **2026-09-30 更正**：⚠️ 本文原为"逐步执行计划" ⇒ ⭐ **第 1 / 2 / 4 步【均已执行并实测】**。
> 🔴 **下文的判据【保持有效】**（⭐ 是它们判绿了），⛔ **但"待做"状态已作废** —— ⛔ **勿重做**。

| 步 | 🔴 计划 | ✅ 实际 | ⭐ 证据 |
|---|---|---|---|
| **1 · A** 上行缓冲 | 「新建 `up_ring.c/.h`」 | ✅ **已落地** —— 160 KB in PSRAM，蓄水/放水 | ⭐ `u_in=2000`（🔴 原 `1611`） |
| **2 · E** 一键验收 | 「新建 `e2e_accept.py`」 | ✅ **已落地** —— ⭐ 通过退出码 0 | `esp32/tools/e2e_accept.py` |
| **3 · F** push | 「🔴 需你点头」 | ⏳ **仍待用户同意**（⚠️ 未推数看 `git status -sb`） | — |
| **4 · B** `0xABF3` 子集 | 「🔴 `0xABF3` 现在是**废的**」 | ✅ **已实现** —— `0x01` 清池 · `0x02` 状态→`0xABF4`。🔴 原 `0xABF4` 因 `AUTO_RSP`+`length=0` **读回空**，⭐ 已改 `RSP_BY_APP`<br>🔴🔴 **2026-10-01 更正**：⚠️ 本行原写「**子集**」（⭐ 只有 `0x01`/`0x02`）⇒ 🔴 **已作废**。⭐ **现为七个命令**：`0x01` 清池 · `0x02` 状态上报 · ⭐ **`0x03` 起播** · ⭐ **`0x04` 停止** · ⭐ **`0x20` 屏探针** · ⭐ **`0x21` 原样 HMI 命令** · ⭐ **`0x22` 设曲名**<br>🔴🔴 **2026-10-01 修正：⚠️ 原文写「四个命令」+ 行号 `:606`/`:611`/`:629`/`:634` ⇒ ⭐ 实测 7 个（`ble_main.c` 的 `case 0x01`/`0x02`/`0x03`/`0x04`/`0x20`/`0x21`/`0x22` @ `:659`/`673`/`691`/`696`/`712`/`724`/`753`），⛔ 原行号一个都不对**（⭐ 依据 = 用户 2026-09-30 裁定走模式 B）<br>🔴 另：`0xABF4` **已扩成八行**（+ ⭐ `V1` 行带 `req=`/`up=` ⇒ **陈旧可判定**），且是**【拉取快照】**（⭐ 只有发 `CMD 0x02` 才刷新）<br>🔴🔴 **2026-10-01 修正：⚠️ 原文写「六组」+ 行号 `:613` ⇒ ⭐ 实测格式串 8 行（`ble_main.c:419-435`）、`CMD 0x02` 调用点 @ `:675`** | `ble_main.c` / `gatt_svc.c` |
| **5** 等你接线 | 「🔴 需硬件」 | ✅🔴🔴 **2026-10-01 修正：⚠️ 原文写「⏳ 仍待做（🔴 屏未接）」⇒ 【已作废】** —— ⭐ **串口屏已于 2026-10-01 接上并全链路验收通过**（⭐ 屏上 6 栏全部跟着状态变；`esp32/evidence/串口屏HMI验收报告-20261001.md`）。⚠️ **剩下的只有 FPGA 端到端**（⭐ 等 `G21`/`G22` 分配） | ✅ 屏已接 |
| ⭐ **额外** 反向通路 | ⚠️ **计划未列** | ✅ **已打通** —— 2000 字节 round-trip 逐字节一致 | `esp32/evidence/反向通路验收-ESP32侧-20260930.md` |
| ⭐ **额外** 波特率 | 🔴 **计划全篇未提"降档 500 k"** | 🔴 **= `500000`**（⭐ 计划成文时的 1 Mbps 口径**已作废**） | `ble_config.h` / `uart_test_main.c` / `bridge_config.h` |
| 🔴 **按键脚** | ⚠️ **计划未提** | 🔴 **= `GPIO6`**（⛔ **不是 `GPIO0`**） | `esp32/ble/main/ble_config.h` `BLE_BTN_GPIO 6` |

---

## 〇、⭐⭐ 执行总览（⭐ 5 步）

| 序 | 事项 | ⭐ 依赖 | ⚠️ 风险 | ⭐ 预估 |
|---|---|---|---|---|
| **1** | ⭐ **A：上行缓冲** | ✅ **不依赖任何人** | ⚠️ 中 | ⭐ 长(新模块) |
| **2** | ⭐ **E：一键端到端验收** | ⚠️ 依赖 A(⭐ 为验它) | ⚠️ 低 | ⭐ 中 |
| **3** | ⭐ **F：push** | 🔴 **需你点头** | ⚠️ 低 | ⭐ 短 |
| **4** | ⚠️ **B 子集：`0xABF3` 无争议命令** | ⚠️ **绕开"起播"** ⇒ ✅ 不被阻塞 | ⚠️ 中 | ⭐ 中 |
| **5** | 🔴 **等你接线**（屏 / FPGA） | 🔴 **只有你能做** | — | — |

> ⭐ **原则**：⭐ **每步做完必须过判据才进下一步**（⛔ 不跳步）。
> ⚠️ **每步都改固件 ⇒ 都要重编重烧**。

---

# 第 1 步 ⭐ A —— 实现上行缓冲

## 1.1 ⭐ 为什么做

🔴 **唯一的"静默丢数据"缺口**：⭐ 实测灌 **2000 字节** ⇒ ⭐ 固件**只收到 1611**(`u_rx=1611`) ⇒
🔴 **丢 389 字节,且【无任何报错】**。

⭐ 根因：`GPIO18` 的 UART RX 环形缓冲**仅 1026 字节**(`ble_config.h:117`),
⚠️ 而 `task_uart_to_ble` 搬运时每段要 `vTaskDelay` ≥1 tick(**10 ms**) ⇒ **搬得没比进得快**。

## 1.2 ⭐ 做什么（⭐ 依据 `files/20-代码/上行通路缓冲设计-20260930.md`）

| # | 动作 | ⭐ 细节 |
|---|---|---|
| **A1** | ⭐ **新建 `esp32/ble/main/up_ring.c` + `up_ring.h`** | ⭐ **新建独立模块** —— ⛔ **不复用 `pool.c` 状态**<br>（⭐ 设计文档列了 5 个维度不同：生命周期/消费驱动/单元/满策略/消费者优先级） |
| **A2** | ⭐ **分配策略照搬 `pool_alloc()`** | ⭐ **PSRAM 优先** → ⚠️ 失败降级内部 DRAM → ⚠️ 再不行也不 abort<br>（⭐ 参照 `pool.c:171-193` 的写法） |
| **A3** | ⭐ **容量 = 32 KB** | ⭐ 可 `#ifndef UP_RING_BYTES` 覆盖<br>⭐ 依据：655 ms 线速突发 / **52.4 s** 音乐节拍余量 |
| **A4** | ⭐ **溢出策略 = 丢最旧（drop-oldest）** | ⚠️ **与下行「宁可饿着」方向相反** —— ⭐ 因上行"最新性 > 完整性"<br>⚠️ **必须记账**(`u_drop` / `u_drop_ev`) |
| **A5** | ⭐ **保持单任务** | 🔴 **硬约束：同一个 UART 只能有一个读者**<br>⇒ ⭐ 生产者(`uart_read_bytes`)与消费者(`notify`)在**同一个 `task_uart_to_ble` 里**<br>⇒ ⛔ **不加第二个 `uart_read_bytes` 调用点** |
| **A6** | ⭐ **接进 `task_uart_to_ble`** | ⭐ 位置：`ble_main.c:617` 之后(⭐ 即 `s_uart_rx_bytes += n;` 之后)<br>⭐ 先 **push 进环**,再从环 **pop 出来发 notify**<br>⚠️ **注意 `ble_main.c:642`**：未连接时**仍要 push**(⭐ 只是不发),⛔ 否则丢数据的逻辑就错了 |
| **A7** | ⭐ **8 个可观测字段** | ⭐ `u_in` `u_out` `u_drop` `u_drop_ev` `u_hwm` `u_level` `u_cap` `u_psram`<br>⭐ 全部 `volatile uint32_t`（⭐ 照 `ble_main.c:68-77` 先例） |
| **A8** | ⭐ **加进状态日志** | ⭐ 照设计文档给的格式：<br>`u_rx=%lu u_in=%lu u_out=%lu \| ring=%lu/%lu(%s) hwm=%lu \| u_drop=%lu/%lu \|` |
| **A9** | ⚠️ **`up_ring_reset()`** | ⚠️ 清环 + ⭐ **`u_hwm` 是否清零要标明**（⭐ 设计文档 §六说过要区分） |

## 1.3 ⭐⭐ 验收判据（⭐ 逐条，⛔ 不只看"编译过了"）

| # | 判据 | ⭐ 期望 | 🔴 不满足说明 |
|---|---|---|---|
| **1** | ⭐ **编译** | 零 error 零 warning | — |
| **2** | ⭐ **反向判据**（⭐ 最关键） | 灌 **2000 字节** ⇒ ⭐ **`u_in` 必须 = 2000** | 🔴 若仍 **1611** ⇒ ⭐ **缓冲【没生效】**（⚠️ 这是**证伪**用的，⛔ 不是"看起来对"） |
| **3** | ⭐ **对账** | ⭐ `u_out` 追得上 `u_in`（⚠️ 可能滞后） | 🔴 `u_in − u_out` 持续增 ⇒ ⚠️ BLE 侧发不动 |
| **4** | ⭐ **正常态** | 🔴 **`u_drop=0/0`** | 🔴 非 0 ⇒ 环满 ⇒ ⚠️ 缓冲不够 / FPGA 超发 |
| **5** | ⭐ **非空洞性** | ⭐ `u_hwm` **≤ 2000**(⭐ 灌了 2000) | ⚠️ 若 `u_hwm` 恒 0 ⇒ 🔴 **环根本没被用上**（⭐ 探针假绿,见 `C83`） |
| **6** | ⭐ **PSRAM 落位** | ⭐ `(PSRAM)` | ⚠️ `(DRAM)` ⇒ ⚠️ 降级了(⭐ 能跑但余量小) |
| **7** | ⭐ **不回归** | ⭐ 下行放水仍 `rate≈1920`、`sent=200` | 🔴 变了 ⇒ ⚠️ 改坏了别的东西 |
| **8** | ⭐ **看门狗** | ⭐ 不触发 | 🔴 触发 ⇒ ⚠️ 查新增延时 |

## 1.4 ⚠️ 失败路径（⭐ 先列出来，免得临场瞎猜）

| 现象 | ⭐ 先查 |
|---|---|
| `u_in` 仍 1611 | ⭐ **push 的位置对不对**（⭐ 必须在 `uart_read_bytes` 之后、notify 之前） |
| `u_in` 涨但 `u_out` 不动 | ⚠️ `s_connected` / `s_handle_noti`（⭐ `ble_main.c:642` 那个判断） |
| `u_hwm` 恒 0 | 🔴 **环没被真正使用**（⭐ 直接写穿到 notify 了？） |
| ⚠️ 编译报未定义 | ⚠️ `esp32/ble/main/CMakeLists.txt` 的 `SRCS` 要**加 `up_ring.c`** |
| 🔴 看门狗 | ⚠️ 新增循环里有没有 <1 tick 的 `vTaskDelay` |

## 1.5 ⚠️ 本步的边界

🔴 **缓冲只吸收【突发】,⛔ 救不了【持续过载】** —— ⚠️ 持续 50 KB/s **23.4 s** 后仍满。
⭐ **根治靠 FPGA 侧按节拍发** ⇒ ⭐ **两者互补,⛔ 不可替代。**

---

# 第 2 步 ⭐ E —— 一键端到端验收脚本

## 2.1 ⭐ 为什么做

⚠️ 现在验收要**手动串 3 步**（清池 → 灌数据 → 触发+抓包）⇒ ⭐ 每次联调都重复,⚠️ 且判据**靠人记**。

## 2.2 ⭐ 做什么

| # | 动作 | ⭐ 细节 |
|---|---|---|
| **E1** | ⭐ **新建 `esp32/tools/e2e_accept.py`** | ⭐ 一条命令串完整流程 |
| **E2** | ⭐ **步骤** | ① `R` 清池 → ② BLE 灌 N 帧 → ③ 读日志确认 `pool=N` → ④ 起播(`S`) → ⑤ 抓 `GPIO17` → ⑥ **打印判据对账表** |
| **E3** | ⭐ **复用已有工具** | ⭐ 灌数据 = `send_frames_ble.py` 的逻辑;⭐ 抓包 = `trigger_and_capture.py` 的逻辑<br>⚠️ **但要注意**：⭐ **两者抢同一个串口**(⭐ `COM31`) ⇒ ⭐ **必须单进程单句柄**(见 `C101`) |
| **E4** | ⭐ **输出对账表** | ⭐ `total/tf/rst/unk/ovf/mismatch/clamp` + ⭐ **`sent`** + ⭐ **`rate≈1920`** + ⭐ **`u_in/u_out/u_drop`** |
| **E5** | ⭐ **退出码** | ⭐ 0 = 全绿;⭐ 非 0 = 指出**哪条不过** |

## 2.3 ⭐ 验收判据

| # | 判据 | ⭐ 期望 |
|---|---|---|
| **1** | ⭐ **一条命令跑完** | ⭐ 不需要人工干预(⭐ 除了接线) |
| **2** | ⭐ **全绿时退出码 0** | ⭐ `echo $LASTEXITCODE` = 0 |
| **3** | ⭐⭐ **能判红**（⭐ 非空洞性） | 🔴 **故意不灌数据就起播** ⇒ ⭐ **必须判红**（⚠️ 不能"永远绿"） |
| **4** | ⭐ 在 GBK 控制台**不崩** | ⭐ 强制 UTF-8 输出(⭐ 照 `send_frames_ble.py` 的写法) |

---

# 第 3 步 ⭐ F —— push 未推的提交

## 3.1 ⭐ 待推清单（⭐ 5 个）

| 提交 | 内容 |
|---|---|
| `0edae6e` | 验收报告更新(pace 结论更正) |
| `46fb1b5` | 🔴 **`gatts_if` 修复**(反向通路跑通) |
| `690d644` | 延时陷阱 + 压力测试发现 + 两端文档 |
| `c6112f9` | 上行缓冲设计 + 机制更正 |
| `d4bb533` | ESP32 侧工作计划 |

⚠️ **加上 A / E 完成后会再多 1~2 个** ⇒ ⭐ **建议 A、E 做完再一起压**。

## 3.2 ⭐ 流程（⭐ 按纪律 0.7）

```powershell
git fetch origin                       # ⭐ 0.3 先同步
git log --oneline origin/feat/s3-ble..HEAD   # ⭐ 看清要压什么
git diff --name-only origin/feat/s3-ble..HEAD # ⭐ 敏感文件检查
git tag pre-squash/2026-09-30d         # ⭐ 备份 tag(⚠️ c 已用)
git tag --points-at HEAD               # 🔴🔴 2026-10-01 修正：⭐ 必须【核对非空】！
#   ⚠️ 理由：⭐ ref/tag 是【22 个 worktree 共享】的命名空间 ⇒ `pre-squash/<日期>` 很可能
#   🔴 已被【另一条线】占用 ⇒ ⚠️ 而"存在就跳过"的守卫会【静默跳过】⇒
#   ⭐ 结果 HEAD 根本没被钉住，脚本却继续往下走（⭐ 实测踩过：`pre-squash/2026-10-01` 已被占用）。
#   ⛔ 判据是【`git tag --points-at HEAD` 非空】，⛔ 不是"`git tag` 命令没报错"。
git bundle create "…\_备份\…bundle" --all  # ⭐ 仓库外副本
git reset --soft origin/feat/s3-ble   # ⭐ 压
git commit -m "<总纲>" -m "<明细>"      # ⭐ 一个提交
git push origin feat/s3-ble            # ⭐ 显式分支,⛔ 不带 --tags/--all
```

⚠️ **注意**：⭐ **代理** —— ⚠️ 若再报 `127.0.0.1:7890` 连不上 ⇒ ⭐ 用
`git -c http.proxy= -c https.proxy= push …`（⭐ 单次覆盖,⛔ 不动全局配置）。

## 3.3 ⭐ 判据

| # | 判据 | ⭐ 期望 |
|---|---|---|
| **1** | ⭐ **`ahead/behind`** | ⭐ **`0 0`** |
| **2** | ⭐ **tree hash 一致** | ⭐ 压缩前后**同一个 tree**（⭐ 证明内容零丢失） |
| **3** | 🔴 **备份 tag 未泄露** | ⭐ `git ls-remote --tags` **无 `pre-squash`** |
| **3b** | 🔴🔴 **HEAD 真被 tag 钉住**（⭐ 2026-10-01 修正**新增**） | ⭐ **`git tag --points-at HEAD` 非空**（⛔ **不是**"`git tag` 命令没报错" —— ⚠️ 因 ref 是**共享命名空间**，⭐ tag 名很可能已被**另一条 worktree** 占用 ⇒ "存在就跳过"会**静默跳过**） |
| **4** | 🔴 **敏感文件** | ⭐ 无 `备料`/`xlsx`/`names.local` |
| **5** | 🔴 **未越界** | ⭐ **无 `rtl/` `constr/` `tb/` `sim/`** 改动 |

---

# 第 4 步 ⚠️ B 子集 —— `0xABF3` 的**无争议命令**

## 4.1 ⭐ 为什么只做子集

🔴 **原文写「`0xABF3` 现在是废的」—— 🔴🔴 2026-09-30 更正：⚠️ 该断言已作废** ✅
⭐ **原文**：「`ble_main.c:367`：写 `0xABF3` 与 `0xABF1` **走同一段代码** ⇒ ⚠️ 被当**曲谱数据**塞进缓冲」
✅ **现状**：⭐ **已剥离分支 + 实现命令解析**（`0x01` 清池 · `0x02` 状态上报）⇒ ⛔ **不再被当曲谱数据**。

🔴 **但完整命令语义 = "起播归属"** ⇒ ⚠️ **被架构裁定阻塞**（⭐ 方案③ vs 模式B）。

⇒ ⭐ **先做【与架构无关】的那部分**：

| 命令 | ⭐ 语义 | ⚠️ 有争议吗 |
|---|---|---|
| ⭐ **`0x01` 清池** | `pool_reset()` | ✅ **无争议** |
| ⭐ **`0x02` 读状态** | 触发一次状态上报 | ✅ **无争议** |
| 🔴 ~~`0x03` 起播~~ | `pool_start()` | 🔴 **有争议** ⇒ ⛔ **本步不做** |

## 4.2 ⭐ 做什么

| # | 动作 | ⭐ 细节 |
|---|---|---|
| **B1** | ⭐ **剥离分支** | ⭐ 把 `h == s_handle_cmd` 从 `ble_main.c:367` 那个 `if` 里**拿出来**,⭐ 单独处理 |
| **B2** | ⭐ **加解析** | ⭐ 单字节命令；⚠️ **未知命令要计数**(⭐ 别静默吞) |
| **B3** | ✅ **配套 `0xABF4`(STAT) 上报 —— 【已完成】** | 🔴🔴 **2026-09-30 更正**：⚠️ 原文写「现在 `gatt_svc.c:157` 注册了**但从未被写**」⇒ 🔴 **已作废**：⭐ **已可读**（🔴 原坏因 `ESP_GATT_AUTO_RSP` + `length=0` ⇒ **读回空**；⭐ 改 `ESP_GATT_RSP_BY_APP`）<br>🔴🔴 **2026-10-01 再更正**：⚠️ 现值不是短格式 —— ⭐ **六组**（`V1 mode=`/`pool=`/`ring=`/`ble=`/`uart=`/`frame=`/`cmd=`，`ble_main.c:336`），🔴 **且是【拉取快照】**（⭐ 只有先发 `CMD 0x02` 才刷新，⭐ 截至 `35036bf` 在 `:613`）<br>⭐ **2026-10-01 起 `V1` 行带 `req=`/`up=`** ⇒ ⭐ **陈旧【可判定】**（提交 `35036bf`）；🔴 **尺寸警告**：⭐ 样本 **261 B** > `char buf[256]`（`:352`）⇒ ⚠️ **可能截断尾部** |
| **B4** | ⭐ **命令表写进文档** | ⭐ 否则下一个人不知道发给谁 |

## 4.3 ⭐ 验收判据

| # | 判据 | ⭐ 期望 |
|---|---|---|
| **1** | ⭐ 写 `0x01` ⇒ 池清空 | ⭐ 日志 `pool=0` |
| **2** | ⭐ 写 `0x02` ⇒ 能读回状态 | ⭐ 含 `pool=`/`sent=` |
| **3** | 🔴 **写 `0xABF1` 的曲谱数据不受影响** | ⭐ 灌 200 帧 ⇒ `pool=200`(**⛔ 不能被当命令**) |
| **4** | ⚠️ 未知命令 | ⭐ 计数 + 日志,⛔ 不静默 |

---

# 第 5 步 🔴 等你接线（⛔ 我做不了）

| # | 事项 | ⭐ 接上后我做什么 |
|---|---|---|
| **1** | 🔴 **串口屏 + 5V** | ⭐ 验 HMI 397 行代码(⭐ **从未真机跑过**)：`t0~t4` 显示、`j0/n0` 进度、`t3` 蓝牙状态 |
| **2** | 🔴 **FPGA** | ⭐ 验**端到端出声** —— ⚠️ **FPGA 侧的上行发送模块是否就位以 `rtl/` 为准**。<br>🔴🔴 **2026-09-30 更正**：⚠️ 原文写"需 FPGA 侧**先有 `uart_tx.v`**(⭐ 上行)"⇒ 🔴 **ESP32 侧这部分已不成立**：⭐ **写 `GPIO18` 的 2000 字节 ⇒ BLE `0xABF2` 逐字节一致**（`esp32/evidence/反向通路验收-ESP32侧-20260930.md`） |
| **3** | ⭐ **判据** | ⭐ 屏：⭐ 进度条会动、百分比非 0(⛔ 不是 `x/0`)<br>⭐ FPGA：⭐ 按起播键**真的出声** |

---

## 附一、⚠️ 全程纪律（⭐ 别忘）

| # | 纪律 |
|---|---|
| **1** | 🔴 **只改 `esp32/`** —— ⛔ **不碰 `rtl/` `constr/` `tb/` `sim/`**（⭐ 另一条线） |
| **2** | ⭐ **每步做完 commit**（⭐ 本地 commit 不限次数） |
| **3** | 🔴 **push 必须先问** |
| **4** | ⭐ **改完必重编重烧**,⭐ 且**烧录会清空池** ⇒ ⚠️ 测试前**要重新灌数据** |
| **5** | ⭐ **端口会漂** —— ⛔ 不写死 `COM29`/`COM31` |
| **6** | ⭐ **一次只改一个变量** |
| **7** | ⚠️ **`-D` 开关改了要【删 `build/`】**（⭐ `C99`/`C61`：CMake 缓存会粘住） |

## 附二、⭐⭐ 每一步的"红→绿"判据一览

| 步 | 🔴 改之前应该是**红**的 | ✅ 改之后应该是**绿**的 |
|---|---|---|
| **A** | ⭐ `u_in=1611`(丢 389) | ⭐ **`u_in=2000`**、`u_drop=0/0`、`u_hwm≤2000` |
| **E** | ⚠️ 要手动串 3 步 | ⭐ **一条命令 + 退出码 0** |
| **F** | ⭐ `ahead 5` | ⭐ **`0 0`** |
| **B** | ⭐ 写 `0xABF3` **无任何效果** | ⭐ **清池生效 + 能读状态** |

> ⭐⭐ **注意 A 的判据**：⚠️ **`u_in=1611` 是【能证伪】的** ——
> ⭐ 若改完**仍 1611**,⇒ ⭐ **说明缓冲没生效**,⛔ **不是"看起来对"**
> （⭐ 这是 `C83`「探针假绿」的**反向用法**：⭐ **先确认判据能失败**）。

## 附三、⚠️ 本计划的边界

| # | 说明 |
|---|---|
| **1** | 🔴🔴 **【2026-09-30 已执行，⛔ 勿重做】** —— ⚠️ 原文写"本文件⛔ 不含代码"（⭐ 现代码已落地：`up_ring.c/.h` · `e2e_accept.py` · `0xABF3` 解析） |
| **2** | 🔴 **A 不能替代 FPGA 侧限速** |
| **3** | 🔴 **B 的"起播"部分⛔ 不做** —— ⚠️ 等裁定 |
| **4** | 🔴 **第 5 步的联调⛔ 不在我能力内** |
| **5** | ⚠️ **每步都会让板子固件变化** ⇒ ⭐ **与已推送版本不同** |

---

## 附 · 证据索引

**设计 / 裁定单**
`files/20-代码/上行通路缓冲设计-20260930.md`（⭐ A 的完整依据）·
`files/20-代码/反向通路对接单-给FPGA侧-20260930.md` ·
`files/20-代码/矛盾裁定单-方案3与模式B-20260930.md`（🔴 阻塞 B 的起播部分）·
`files/20-代码/ESP32侧工作计划-20260930.md`（⭐ 分类版）

**实测**
`esp32/evidence/反向通路验收-ESP32侧-20260930.md`（⭐ 含丢字节限制）·
`esp32/evidence/放水时序验收报告-20260930.md`（⭐ `rate=1919`）

**代码位置**
`esp32/ble/main/ble_main.c:367`（🔴 CMD 与 RECV 同路径）· `:607`（`task_uart_to_ble`）·
`:613`（唯一读口）· `:617`（`u_rx` 计数）· `:642`（未连接判断）·
`esp32/ble/main/ble_config.h:117`（⚠️ RX 缓冲 1026 B）·
`esp32/ble/main/pool.c:171-193`（⭐ PSRAM 优先分配,照搬它）·
`esp32/ble/main/gatt_svc.c:157`（⚠️ STAT 已注册未使用）·
`esp32/ble/main/CMakeLists.txt`（⚠️ 新文件要加进 SRCS）
