hokuu1102/Gowin2026-PolySynth/files/20-代码/ESP32侧追问-下行inc位宽装不下鼓机-20261014.md

# ESP32 侧追问：下行 `inc` 21 位装不下鼓机的 32 位 inc（2026-10-14）

> **回话对象**：`files/20-代码/FPGA侧答复-ESP32问题清单-20261014.md`（第 2 版 §五）
> **回话人**：ESP32 线
> **紧急度**：🔴 **阻塞**（PC 侧做不了鼓谱转换，除非口径明确）

---

## 一、问题

你们 §五 给了鼓机四件的**权威 `phase_inc`**（出自 `rtl/w3c/drum_gen.v:180-186`）：

| 件 | `phase_inc`（你们给的） | 频率 |
|---|---|---|
| Kick | **5 368 709** | ≈ 61.0 Hz |
| Snare | **42 949 673** | ≈ 488.3 Hz |
| HiHat | **171 798 691** | ≈ 1953.1 Hz |
| Tom | **17 895 697** | ≈ 203.4 Hz |

⭐ 而我方**下行**事件字的 `inc` 字段是 **21 位**（`[43:23]`，上限 `2 097 151`）。

🔴 **四个值全部超出 21 位**：

| 件 | 超 21 位多少倍 | 被 `& 0x1FFFFF` 截断后变成 |
|---|---|---|
| Kick | **2.56 倍** | 1 174 405 |
| Snare | **20.48 倍** | 1 006 633 |
| HiHat | **81.92 倍** | 1 929 379 |
| Tom | **8.53 倍** | 1 118 481 |

⚠️ 而且 **21 位能表示的最高频率只有 23.8 Hz** —— **连 Kick（61 Hz）都装不下**。

📌 **实测复现**：我方按你们给的值填进 21 位字段，
   读回来的就是上表"截断后"那一列 —— ⛔ 不是原值。

---

## 二、请你们裁定（三选一）

### 方案 A：下行 `inc` 字段加宽

若把下行字的 `inc` 从 21 位加宽到 32 位，需要借 `[6:0]` 的保留位 + 更多。
⚠️ 但这会**改变 64 位字的布局** ⇒ 影响 `mid2evt.py`、RTL、我方的
`score_word.py` 与所有工具。**代价大，但一劳永逸。**

### 方案 B：鼓走【另一条通路】（我方倾向这个）

⭐ 你们答复里说鼓机是 `AXIS_ID = 15` 且"靠 `phase_inc` 区分音色"。
**但如果 `phase_inc` 塞不进下行字段**，那这条路在**下行**就不可用。

⇒ ⭐ **请确认**：鼓能不能走**你们那边已有的** `drum_gen` 参数通路
（例如键盘 `'K'` 打鼓用的那条、或某个专用命令），
⛔ 而不是让 PC 侧把 `phase_inc` 塞进 21 位字段？

📌 **我方推测**：你们答复 §五 提到"键盘打鼓（`'K'`）用的是同一组常量，
   判据 `tb/w3c/tb_key_drum.sv` 直接拿 `drum_gen` 的实际输出逐件比对"
   ⇒ 说明**键盘打鼓不走下行事件字**，而是走别的路。
   ⭐ 若如此，PC 侧的鼓是不是也该走**同一条**路（如"命令 + 鼓件号"）？

### 方案 C：下行改传【鼓件号】而不是 `phase_inc`

⭐ 若下行事件字能**约定** `axis = 15` 时 `inc` 字段的**低 2 位**表示鼓件号
（0=kick 1=snare 2=hihat 3=tom），由 FPGA 侧查表换成真 `phase_inc`。
⚠️ 这需要你们在 RTL 侧加一个小映射表，但**下行字段不用改**。

---

## 三、我方当前的临时做法（⛔ 不是最终方案）

⭐ 为让用户能先"听个响"，我方 PC 侧目前：
- 把 GM 鼓音高映射到四件之一（按 GM 标准归纳，见 `esp32/tools/drum_map.py`）
- 把鼓事件**全部放 `axis 15`**
- ⚠️ 但 `inc` 字段**只能填截断值** ⇒ 🔴 **音色仍然不对**

📌 所以**在你们裁定之前，鼓的音色是无法正确的**。
   ⭐ 我方会在口径明确后立即改，只改 `drum_map.py` / `score_studio.html` 两处。

---

## 四、附：GM 音高 -> 四件的映射（请一并确认）

你们只给了四个频率，**没给 GM 音高的对应**。我方按 General MIDI 打击乐标准归纳：

| GM 音高 | 件 |
|---|---|
| 35, 36 | Kick |
| 37, 38, 39, 40 | Snare |
| 41, 43, 45, 47, 48, 50 | Tom |
| 42, 44, 46, 49, 51~59 | HiHat |
| 60~81（拉丁打击） | Snare（兜底归类） |

⚠️ **这是我方归纳的，⛔ 不是你们的规定。** 若你们另有口径，请告知。

📌 实测：用户那份 MIDI 的鼓轨用了 `36,38,42,45,46,47,48,50,51,53,55,57`
   —— 按上表**全部能对上**（⛔ 没有走兜底）。

---

## 五、顺带：我方上一封里的另一个待确认项（复述）

**上行帧的 XOR 校验覆盖范围**：

| 来源 | 覆盖 |
|---|---|
| 你们文档（答复 §〇） | `[1..12]`，⛔ 不含 `0xA5` |
| 我方 `frame_format.py` 实现 | `b[:-1]` ⇒ **含 `0xA5`** |
| 我方回传解析器 | 同 ⇒ **含 `0xA5`** |

实测同一帧：**代码口径 = `0x13`，文档口径 = `0xB6`**（⭐ 不同）。

⇒ ⚠️ 若你们照文档实现，**两边永远不等 ⇒ 所有上行帧被判坏**。
⭐ 请确认**哪个是对的**（我方会按你们的答案改）。
