hokuu1102/Gowin2026-PolySynth/files/20-代码/ESP32线交接文档-20261001.md

# ESP32 线交接文档 —— 2026-10-01

> **交接人**：ESP32 线（本会话）
> **接手人**：下一个会话 / 子代理
> **仓库 / worktree**：`C:\Users\hokuu\Desktop\FPGA\FPGA2026-esp32`
> 🔴🔴 **2026-10-01 修正（⭐ 第三轮文档审计）：⚠️ 原文写「⭐ **⛔ 不是 `FPGA2026`**，⭐ 两个同时开着，⭐ 这是头号混淆源」⇒ 该措辞把两者说成了【两个独立仓库】，🔴 【实测不成立】。**
> ⭐ **真实关系 = 【同一个 git 仓库的两个 `git worktree`】**（⭐ 表述对齐 `esp32/README.md:81-89`）。⭐ 实测三条：
> · ⭐ 本目录的 `.git` 是一个**文件**（⛔ 不是目录），内容 = `gitdir: C:/Users/hokuu/Desktop/FPGA/FPGA2026/.git/worktrees/FPGA2026-esp32`
> · ⭐ `git rev-parse --git-common-dir` = `…/FPGA2026/.git` ⇒ 🔴 **与 `FPGA2026` 是同一个 `.git`**
> · ⭐ `git worktree list` = **22 个 worktree 共用这一个 `.git`**
> ⚠️ **由此推出的两条（⭐ 这才是要记住的，⛔ 不是"两个仓库"）**：
> · 🔴 **分支 / tag / 远端跟踪 ref 是【共享命名空间】** ⇒ ⛔ **不能假设"我在 A 里打 tag / 改分支不影响 B"**（⭐ 实测踩过：`pre-squash/2026-10-01` 已被**另一条线**占用 ⇒ 备份脚本的"存在就跳过"守卫让它**静默跳过**，⚠️ HEAD 其实没被钉住）
> · ✅ **`HEAD` / 索引 / 工作区是【各自】的** ⇒ ⚠️ **正因为"切分支互不干扰"，反而更容易误以为整体隔离**
> ⚠️ **仍然存在的真实混淆点**：⭐ 两个目录的 `rtl/` **内容不同**（⭐ 本 worktree 是**旧快照**）⇒ ⭐ **核对 FPGA 侧一律去 `FPGA2026`（main）**，⛔ 别用本 worktree 的 `rtl/` 下结论。
> **分支**：`feat/s3-ble`
> **当前状态**：⭐⭐ **串口屏 HMI 全链路通过** —— 4 个死功能已修，⭐ 19 个工具 / 317 项 / 0 RED

---

## 〇、⭐⭐ 硬边界（⭐ 先看这条，⛔ 违反会毁掉队友的工作）

| ⭐ 本会话**可以**改 | ⭐ **只读**（⭐ 属 FPGA 线） |
|---|---|
| `esp32/**` | 🔴 `rtl/**` · `constr/**` · `tb/**` · `sim/**` |
| `files/**`（⭐ 文档） | 🔴 `bringup/**` |

⚠️ **`rtl/` 下的一切改动都归 FPGA 线** —— ⭐ 我这边**只能读**。
⚠️ 另有一个**公开仓库** `C:\Users\hokuu\Desktop\经验`（⭐ 经验库），⭐ 规则见 §六。

---

## 一、⭐⭐ 当前**已通**的东西（⭐ 都带判据，⛔ 不是"应该能行"）

| ⭐ 通路 | ⭐ 判据 | ⭐ 状态 |
|---|---|---|
| ⭐ **PC → BLE → ESP32 → 水池** | ⭐ 灌 200 帧 ⇒ `sent=200` · `ovf/late/mm=0` | ✅ |
| ⭐ **ESP32 → UART1 → 〔CH340 USB-TTL〕** | ⭐ 972 B / 108 帧，⭐ 序号 `0..107` 完整 | ⚠️ **仅 ESP32 侧**（🔴🔴 **2026-10-01 修正**：⚠️ 原文写「ESP32 → UART1 → **FPGA**」+ `✅` ⇒ 🔴 **对端是 CH340，⛔ 不是 FPGA**） |
| ⭐ **〔跳线/上位机〕→ `GPIO18` → ESP32 → BLE → PC** | ⭐ 2000 B **逐字节相同** | ⚠️ **仅 ESP32 侧（桩注入）**（🔴🔴 **2026-10-01 修正**：⚠️ 原文写「**FPGA** → UART1 → ESP32 → BLE → PC」+ `✅` ⇒ 🔴 **对端是桩，⛔ 不是 FPGA**） |
| ⭐ **ESP32 → UART2 → 串口屏** | ⭐ 屏上 **6 栏**全部跟着变 | ✅ |
| ⭐ **串口屏 → ESP32** | ⭐ `hmi.rx` 涨（⭐ 含触摸事件 `0x65`） | ✅ |
| ⭐ **模式 B 二级水池** | ⭐ 按音乐 tick 放水，⭐ 实测 ~1920 tick/s | ✅ |
| ⭐ **屏上状态机** | ⭐ **6/6** 状态逐个 `get` 读回正确 | ✅ |
| ⭐ **屏上曲名** | ⭐ CMD `0x22` ⇒ **7/7** 用例 | ✅ |

> 🔴🔴 **本表口径（⭐ 2026-10-01 修正，⭐ 接手人必读）**：
> ⭐ **本表凡涉及 FPGA 的行，对端均为【CH340 USB-TTL / 跳线桩】，⛔ 不是真 FPGA。**
> 🔴 **ESP32 ↔ FPGA 端到端【一次都没跑过】** —— ⭐ 依据（⭐ 全部是报告**自述的范围**，⛔ 不是我的推断）：
> · ⭐ `esp32/evidence/UART验收报告-20260930.md:3`：「**目的**：⭐ **证明「ESP32 从 `GPIO17` 发出的字节是正确的」**（⚠️ **不上 FPGA**）」
> · ⭐ `esp32/evidence/反向通路验收-ESP32侧-20260930.md:5`：「**范围**：⚠️ **只证明 ESP32 侧** —— 🔴 **不证明 FPGA 能发**」
> · ⭐ `files/20-代码/降档请求单-1M到500k-20260930.md:218`：「CH340 @1 Mbps ｜ 972 字节，序号 0..107 零缺口 ｜ 🔴 那是 **USB-TTL + 短线**，⛔ **不是 FPGA 链路**」
> · ⭐ 操作步骤文件名就叫 `esp32/UART验证-不上FPGA.md`；⭐ `esp32/README.md:176`：「PC ──USB-TTL──> ESP32 的 UART1 RX ← ⚠️ **不接 FPGA 时，用 USB-TTL 当"假 FPGA"**」
> · ⭐ `files/20-代码/ESP32侧再回函-20261001.md:15`（⭐ **同一时期**）：「🔴 `PMOD0`（含 `G21`/`G22`）未分配 ⇒ **ESP32 ↔ FPGA 一根线都没有**」
>
> ⚠️ **后果（⭐ 这才是要记住的）**：⛔ **不要以为"只剩接根线"** —— ⭐ 这条链路**整条一次都没跑过**，
> ⇒ ⭐ **首次联调要按"新链路"准备**（⭐ 波特率/引脚/电平/帧边界/反向时序**全部未在真硬件上验过**）。
> ⚠️ **另一条同族缺口**：⭐ 上述两份报告的**原始存证（`*.bin` / `*.log`）被 `esp32/.gitignore:19`(`*.bin`) / `:46`(`*.log`) 挡住、从未入库**
> ⇒ ⭐ **结论可入库、原始存证不可入库 ⇒ 判据不可复核**（⭐ 详见 `esp32/evidence/UART验收报告-20260930.md:10-42`；⚠️ 那是**仓库策略**问题，⛔ 需用户裁定，⭐ 本会话未擅改）。

---

## 二、⭐⭐ 关键事实表（⭐ 改代码前必看）

| ⭐ 已通 | ⭐ 判据 |
|---|---|
| ⭐ **上行（FPGA → ESP32）14 B 实时事件帧** —— 解析侧 | ⭐ 离线自检 28 项全过（`_upstream_parse_check.js`）<br>⭐ 含：帧头/类型/seq/tick/axis/inc/vel/校验、跨包分片、表同步 68 B、`0x05` 锚点 |
| ⭐ **下行校验口径（XOR）** | ⭐ **含 `0xA5`**（`b[:-1]`）—— FPGA 侧第 3 版答复**确认以我方为准**，他们改 |
| ⭐ **鼓谱转换** | ⭐ 四件字段值 `>>10` 与 FPGA 表格**逐位一致**；GM 映射他们确认采用 |
| ⭐ **和弦** | ⭐ 分轴后"真同时" ≤ 1（不会被 `same_hit` 顶掉） |

⚠️ **上行仍【未联调】**：FPGA 侧模块已落地（30 条判据全绿）＋ `seq_arb` 鼓来源已改，
   ⏳ **但还没出含这些改动的位流** ⇒ ⭐ 真机联调待他们通知。

### 引脚 / 端口

| ⭐ 用途 | ⭐ 引脚 | ⭐ 参数 |
|---|---|---|
| ⭐ UART1 → **FPGA** | ⭐ TX `GPIO17` · RX `GPIO18` | ⭐ **500000** 8N1 |
| ⭐ UART0 日志 | ⭐ `GPIO43`/`GPIO44` | ⭐ 115200 |
| ⭐ UART2 → **串口屏** | ⭐ TX `GPIO4` · RX `GPIO5` | ⭐ 115200 |
| ⭐ 起播按键 | ⭐ `GPIO6` | ⭐ 按下起播 |
| ⚠️ WS2812 | ⭐ `GPIO48` | 🔴 **必须保持关闭**（⭐ 见 §五） |

⚠️ **串口号会漂** ⇒ ⭐ 一律**按 VID 自动找**：⭐ ESP32 = `VID_303A`（⭐ 常用 `COM29`）；
⭐ 屏 = `VID_FAED`；⭐ CH340 = `VID_1A86`。

### 协议

| ⭐ 项 | ⭐ 值 |
|---|---|
| ⭐ 下行帧 | ⭐ **9 字节**：`0xA5` + 8 B 大端字 |
| ⭐ 字布局 | ⭐ `tick[63:44]20b inc[43:23]21b axis[22:19]4b vel[18:11]8b kind[10:9]2b timbre[8:7]2b [6:0]保留=0` |
| 🔴 字布局的唯一真源 | `esp32/tools/score_word.py`（⭐ 与 `FPGA2026/rtl/top.v:3594-3616` 的六个切片**逐位一致**） |
| ⚠️ `kind` 语义 | ⭐ `0`=note_on · `1`=note_off · **`2`=换速（tempo）** —— ⚠️ 此时 `inc` 被**重解释**为 `tick_inc`（⭐ `pool.c:699-706` 会据此**重锚时间基准**）· `3`=未使用 |
| ⭐ 总数帧 | ⭐ 帧头 `0x00` + 8 B 大端**事件数** |
| ⭐ 复位标记 | ⭐ 9 字节全 `0xA5`（⭐ 固件**吃掉**，⛔ 不转发） |
| ⭐ 音乐时间 | ⭐ PPQN **960** · **120 BPM** ⇒ **1920.003 tick/s** |
| ⭐ 相位换算 | ⭐ `f = inc × 50e6 / 2³²` ⚠️ **⛔ 不是 48.828 kHz**（⭐ 差 1024 倍） |

> 🔴🔴 **2026-10-01 更正：本行原写 `inc[43:22] axis[21:18] vel[17:11] kind[10:9] timbre[8] rsvd[7:0]` —— 那是 2026-09-22 修订【之前】的旧布局。**
> ⭐ 三处硬证据都指向新布局：`FPGA2026/rtl/top.v:3594-3616`（`score_evt_inc = eu_evt_data[43:23]` 等六个切片）·
> `esp32/ble/main/pool.c:60-63`（`inc [43:23]`）· `FPGA2026/tools/mid2evt.py:54-61`（标注「REVISED 2026-09-22」）。
> ⚠️ **旧布局的后果**（按旧布局打包时）：FPGA 解出 `inc>>1`（**低一个八度**）、且 `inc` 的最低位**渗进 `axis`** 把轴号污染、力度丢最高位、音色只剩 1 位。
> ⚠️ **为什么长期没被发现**：ESP32 侧固件只读 `tick[63:44]` 与 `kind[10:9]`（两个布局这两个字段恰好相同），
> 而 `e2e_accept.py` 的判据是 `sent/ovf/late/mm` 这类**传输层计数**，⛔ 根本不解码 `inc/axis/vel/timbre`。
> 🔴 **本行错位域曾同时存在于 3 个地方**：`send_frames_ble.py`（**主用的 BLE 路径**）· `screen_demo.py`（其自检还把 22 位宽**固化成了判据**）· **交接文档自己**（⚠️ 文档错会误导新工具）。
> ✅ **修法**：位域收进 `esp32/tools/score_word.py` 作**唯一定义处**，两个发送工具与演示工具都 import 它 ⇒ ⭐ **"再次漂移"在结构上不可能发生**。

### GATT

### ⭐⭐ `axis` 的两条**必须知道**的语义（🔴 2026-10-14，改过一次行为）

| # | 事实 | 出处 |
|---|---|---|
| **1** | ⭐ **`axis` 对曲谱事件只是【标签】** —— 音高由 `inc` 字段直接携带 | FPGA 侧 `seq_arb.v:333`：`evt_axis_o <= pop_data[AX_O +: AXIS_W]` |
| **2** | 🔴 **同一个 `axis` 上、同一来源的音会【互相顶掉】** —— `note_manager` 里每个 `(axis, src)` **最多只有 1 个在响**的 voice（同源 `note_on` 被 `same_hit` 命中 ⇒ 走复用） | `note_manager.v:870` ＋ `same_hit[sg] = live_mask & (axis_r==cur_axis) & (src_r==cur_src)` |

⇒ ⭐⭐ **所以：和弦的每个音必须落在【不同的 axis】上**（否则只有 1 个音发声）。

📌 **我方实现**：`score_studio.html` 的 `midiToWords()` 里
   —— 把音符**配对成段**，再对段做**贪心 axis 分配**（不重叠的段共用一条轴，重叠的必须分开）。
   ⚠️ 分配时**避开 `12..15`**（`seq_arb.v:204` 用它判鼓）。
   📌 实测用户那份谱子：旋律轴"真同时" **9 → 1**，和弦 526 处全部保留。
   📌 峰值并发 10。
   > ⭐ **2026-10-15 方案 B 更新**：鼓改成**四件各占一条轴**（12/13/14/15）⇒ 旋律可用轴
   > 从 15 条降到 **12 条**（0..11）。实测三份真实谱面峰值并发 **13 / 13 / 10** ⇒ 12 条不够，
   > 所以同时加了**齐奏去重**（同音高+同时值+同音色只发一次）⇒ 峰值降到 **11 / 11 / 10** ⇒ 够用。
   > 详见 `files/20-代码/ESP32侧改动清单-鼓机方案B（四件分轴）-20261015.md`。

🔴 **反面教训（原写法为什么错）**：原来按**音色**归组轴
   （Guitar I/II/III 全是 GUITAR ⇒ 全合并到 `axis 0`）
   ⇒ 6 音和弦只剩 1 个音 ⇒ ⭐ 用户报"**和弦没被识别到**"。

### ⭐ 鼓（2026-10-14）

| 项 | 值 |
|---|---|
| 四件 | **Kick / Snare / HiHat / Tom** |
| `phase_inc`（32 位） | 5 368 709 / 42 949 673 / 171 798 691 / 17 895 697 |
| ⭐ **下行要填的值** | **各 `>> 10`** = **5243 / 41943 / 167772 / 17476** |
| 轴 | ⭐ **四件各占一条轴：Kick 12 · Snare 13 · HiHat 14 · Tom 15**（2026-10-15 方案 B；判据 `axis >= 12`） |
| GM 音高映射 | 见 `esp32/tools/drum_map.py`（FPGA 侧确认采用我方版本） |

🔴 **口径（我错过一次，⭐ 记下来）**：
   下行 `inc` 字段的语义是 **`phase_inc >> 10`（高 21 位）**，
   ⛔ **不是 `& 0x1FFFFF`（低 21 位）** —— 依据 `rtl/top.v:4575`：
   `ps_evt_inc = {1'b0, ps_note_data[43:23], 10'b0}`。
   ⚠️ 我第一版按低 21 位算，得出"21 位装不下"的结论 —— **那个前提是错的**，整张表作废。

⚠️ **待 FPGA 侧确认**：鼓轴上有 **568 次"同 tick 敲 ≥2 件"**（最多 3 件）
   ⇒ 按 `same_hit` 语义可能互相顶掉。已写追问文档
   `ESP32侧追问-同时敲多个鼓与same_hit-20261014.md`。

| ⭐ 用途 | ⭐ UUID |
|---|---|
| ⭐ 服务 | ⭐ `0xABF0` |
| ⭐ 曲谱数据 | ⭐ `0xABF1` |
| ⭐ 通知（上行） | ⭐ `0xABF2` |
| ⭐ 命令 | ⭐ `0xABF3` |
| ⭐ 状态 | ⭐ `0xABF4` |

### ⭐ BPM / tempo（🔴 2026-10-14，两个缺陷叠在一起）

| # | 缺陷 | 根因 |
|---|---|---|
| 1 | 🔴 全局 BPM 的谱子变成 120 | **tempo 轨一个音符都没有** ⇒ `parseMidi` 按"有无音符"过滤轨时**整个被丢** |
| 2 | 🔴 中段变速（rit. / accel.）丢失 | 只发 tick 0 那一帧 `kind=2` |

⭐ **修法**：parse 阶段汇总**全局 `allTempos`**（⛔ 不受轨过滤影响）+
   把**所有** tempo 都发 `kind=2`。
⭐ **FPGA 侧不用改** —— `rtl/w3c/play_seq.v:37-52` 本就支持多处 tempo
   （「手动改速与曲谱 `kind=2` 写同一个寄存器 ⇒ 后写者胜」）。
📌 实测 `09_Conjurer.mid`（168 BPM，7 个 tempo 点）：**7 个全发出**。

### ⭐ 上位机上传通路（🔴 2026-10-14，三个问题）

| 问题 | 根因 | 修法 |
|---|---|---|
| `GATT operation already in progress` | 本页**三处**并发发 GATT（轮询 1.2 s / 灌谱 / 起播停止）⇒ 而 Web Bluetooth 一次只允许一个在飞 | `gattSerial()` **串行队列**；灌谱期间**暂停轮询** |
| 上传只有 **3.6 KB/s** | `CHUNK=180`，而 MTU=517（载荷 514）⇒ 每包只用 180，开销占比过大 | `CHUNK=480`（=9×53，保帧对齐且 ≤514） |
| 🔴 上传**卡死**、无进度条 | `gattSerial` **自嵌套**：`readStat` 内部又入队 ⇒ 自己等自己 | `sendCmd`/`readStat` 改**叶子函数**；加 15 s 看门狗 |

⚠️ **教训**：⭐ 加"串行化"这类**结构性**机制时，
   **必须连它自己的嵌套路径一起想** —— ⭐ 否则治了一种并发、造出另一种死锁。

### ⭐⭐ CMD 命令集（⭐ 写 `0xABF3`）

| ⭐ 命令 | ⭐ 语义 | ⭐ 备注 |
|---|---|---|
| ⭐ `0x01` | ⭐ **复位**（清池 + 屏回 `待机`） | ⭐ 走 `start_action_reset()` |
| ⭐ `0x02` | ⭐ **上报状态**（写 `0xABF4`） | ⭐ **8 组**（`V1`/`pool`/`ring`/`ble`/`uart`/`hmi`/`frame`/`cmd`）<br>🔴🔴 **2026-10-01 修正：⚠️ 原文写「264 B」⇒ ⛔ 该字节数【不可靠】** —— ⭐ 工程里并存 **210 / 221 / 261 / 264** 四个互相矛盾的数（`gatt_svc.c:91`「约 210」· `今晚任务书-20260930.md`「约 221」· `ESP32侧工作计划-20260930.md`「261」· 本文「264」）⇒ ⭐ **权威判据是 `stat_read.py` 的"组齐全"检查**；⭐ 容量真值 = `s_val_stat[320]`（`gatt_svc.c:106`）＋ `char buf[320]`（`ble_main.c:389`） |
| ⭐ `0x03` | ⭐ **起播** | ⭐ 池空则拒绝 |
| ⭐ `0x04` | ⭐ **停止** | ⭐ 屏回 `就绪` |
| ⭐ `0x20` | ⭐ **探针**（发 `get t2/t3/t1/g0.txt`） | ⭐ 台面调测 |
| ⭐ `0x21` | ⭐ **原样发一条 HMI 命令** | ⭐ 台面调测，⛔ 不用重烧 |
| ⭐ `0x22` | ⭐ **设曲名**（UTF-8） | ⭐ 本轮新增 |

### ⭐⭐ 起播提前量（🔴 **最容易算错的一个数**）

```c
/* ⭐ 2026-10-14 起：不再是固定值 —— 由 pool_compute_lead_ticks() 按谱面算 */
#define BLE_POOL_LEAD_TICKS      20000u   /* 仅作【上限】与"极密谱面"的参照 */
#define BLE_POOL_LEAD_MIN_TICKS   1200u   /* 下限：0.625 秒 @120BPM/960PPQN */
#define BLE_POOL_STALL_SEC        0.10f   /* 抗一次 BLE 停顿所需的音乐时间 */
#define BLE_POOL_TICKS_PER_SEC   1920.0f  /* 120BPM / PPQN 960 */
/* FPGA 侧缓冲（他们给的，rtl/w3c/evt_buf.v） */
#define BLE_FPGA_EVT_BUF_DEPTH    1024u
#define BLE_FPGA_EVT_BUF_LOW_WM    256u
#define BLE_FPGA_EVT_BUF_HIGH_WM   768u   /* 安全提前量上限（事件数） */
```

🔴 **池要【先等一段】才发第一帧**（⭐ 预填 FPGA 缓冲，抗 BLE 抖动）。

⭐ **等多少 = 由谱面密度决定** —— 但实测下来基本就是**那个常数**（≈0.1 秒的抗抖动时间），
   再夹到 `[1200, 20000]` 之间 ⇒ **实测用户那份谱子 = `lead 1200 tick`（0.62 秒）**。

📌 **实测（2026-10-14）**：首帧发出用时 **1.81 秒**（原来写死 20000 时是 **10.4 秒**）⇒ ⭐ **快了 5.8 倍**。
   `late=1`（几乎不落后）· `clamp=0`（没被限流）· `rate≈1910`（放水速率正确）。

⚠️ **凡是要"等放完"的地方，⛔ 不能只按谱面时长等** ——
⭐ 一律从 `ble_config.h` **读**这些常数（⭐ `screen_demo.py` 的 `read_lead_ticks()` 是范例）。
⚠️ 更稳的做法是**直接读 `0xABF4` 的 `lead=` 字段**（运行期真值，⛔ 不用猜）。

🔴 **推演过程（连错两次，⭐ 别再走）**：
   · **第一版**按"填满缓冲"算（`lead = HIGH_WM / E`）⇒ 稀谱面算出 **363 秒** ⇒ 荒谬。
   · **第二版**按"攒一次停顿的量"（`lo = N_min / E`）⇒ 🔴 **E 被约掉** ⇒ 恒为常数 192 tick ⇒ 没信息。
   · **第三版（现用）**：承认它**基本就是个常数**（存货深度与消耗速率抵消），
     只在"极密谱面"（`768/E` 小于这个常数）时才往下压。
   📌 见 `esp32/tools/_lead_model_check.py`（7 项自检，把三版都留着）。

---

## 三、🔴 本轮修的**四个死功能**（⭐ 都已实测）

| # | 🔴 症状 | ⭐ 根因（⭐ 都在**上游**） |
|---|---|---|
| **1** | ⭐ 屏上 `播完` **永远显示不出来** | ⭐ `pool_pump()` **已经知道放完了**（⭐ 判据：游标 ≥ 池内帧数），⚠️ **但只打日志** ⇒ 🔴 `s_running` 一直挂 `true` |
| **2** | ⭐ 屏上 `就绪` 语义不符 | ⭐ `hmi.h` 注释写「灌完，等按键起播」，⚠️ 而代码里 `READY` **只有"按 STOP"一个入口** |
| **3** | ⭐ 屏上 `待机` **永远显示不出来** | 🔴 `case 0x01` **绕过 wrapper** ⇒ `hmi_set_state(HMI_ST_IDLE)` 永不执行。⭐⭐ **而真正原因是【前向声明漏了 `reset`】** ⇒ ⚠️ **调不到** wrapper |
| **4** | ⭐ 屏上 `g0` 曲名**永远是 `----`** | 🔴 `hmi_set_song()` **全工程零调用**（⭐ 非 static ⇒ ⚠️ 编译器不报） |

### ⭐⭐ 最值钱的一条教训（⭐ 已录 `C141`）

> ⭐ **追根因时 ⛔ 不要停在"他忘了"** —— ⭐ **要问「他为什么没这么写?」**
> ⭐ 实测：⭐ 绕过封装的**真正原因**是**函数没被前向声明** ⇒ 🔴 **在 C 里调不到**。

### ⭐ 顺手堵掉的一个**真风险**

🔴 曲名会拼进 `g0.txt="<名字>"` ⇒ ⚠️ 含 `"` 会**截断 TJC 命令**（⭐ 多出来的部分被当成**下一条命令** ⇒ 后面全乱）；
⚠️ 含 `0xFF` 会**提前结束**（⭐ TJC 用 `FF FF FF` 当结束符）。
✅ **净化放在 `hmi_set_song()` 源头** ⇒ ⭐ **任何调用方都自动受保护**。

---

## 四、⭐ 工具清单（⭐ 都在 `esp32/tools/`）

### ⭐⭐ 一条命令跑完全部自检（⛔ 不需要硬件）

```powershell
cd C:\Users\hokuu\Desktop\FPGA\FPGA2026-esp32\esp32\tools
python selftest_all.py            # ⭐ 自动枚举，⛔ 不靠人记清单
python selftest_all.py --list     # ⭐ 看会跑哪些
```

⭐ 当前：**19 个工具 / 317 项 / 0 RED**。

### ⭐ 按用途分

| ⭐ 工具 | ⭐ 用途 | ⭐ 要硬件? |
|---|---|---|
| ⭐ `selftest_all.py` | ⭐ 全部自检，⭐ 一个退出码 | ⛔ |
| ⭐ `wrappers_check.py` | ⭐ **检查没人绕过 `start_action_*` 封装** | ⛔ |
| ⭐ `hmi_states_check.py` | ⭐ 逐状态验证屏上 `t1`（⭐ 用 `get` 读回） | ✅ |
| ⭐ `hmi_song_check.py` | ⭐ 曲名 + 净化验证（⭐ 24 自检 + 7 真机） | ⭐ 部分 |
| ⭐ `screen_demo.py` | ⭐ **完整上屏演示**（⭐ 人看 + 读回对照） | ✅ |
| ⭐ `stat_read.py` | ⭐ 读 `0xABF4` 状态（⭐ 先请求再读） | ✅ |
| ⭐ `regress_live.py` | ⭐ 活体回归（⭐ 用**增量**判据） | ✅ |
| ⭐ `e2e_accept.py` | ⭐ 端到端验收（⭐ 200 帧） | ✅ |
| ⭐ `trigger_and_capture.py` | ⭐ 起播触发 + 抓包 | ✅ |
| ⭐ `pool_pace_check.py` / `pool_math_check.py` | ⭐ 水池节奏 / 数学 | ⛔ |
| ⭐ `uart_timing_check.py` / `uart_rx_check.py` | ⭐ 串口时序 | ⭐ 部分 |
| ⭐ `read_log.py` | ⭐ 读串口日志 | ✅ |
| ⭐ `evt2midi/*` | ⭐ 事件录制 → MIDI（⭐ 上位机） | ⛔ |
| ⭐ `_hmi_probe.py` · `_hmi_vis.py` · `_idle_probe.py` · `_lead_probe.py` | ⭐ **`_` 开头 = 一次性排查脚本**（⭐ 不入自检枚举） | ✅ |

### 🔴⚠️ 加新工具时的一条**硬规矩**（⭐ 我踩过两次）

⭐ `selftest_all.py` 是按**源码里有没有 `--selftest` 字面串**判断的
⇒ 🔴 **需要硬件的脚本若不带 `--selftest`，会被当成"直接跑"**
⇒ ⚠️ **`python selftest_all.py` 会真的驱动硬件**。

📊 **实测踩过两次**：

| ⭐ 脚本 | 🔴 自检里干了什么 |
|---|---|
| `rec_upstream.py`（⭐ v1） | ⭐ 真跑了 **30 秒 BLE I/O** |
| `screen_demo.py`（⭐ v1） | ⭐ 真跑完了**整个 45 秒上屏演示**，⚠️ 还改了板子状态 |

✅ **判据**：⭐ **凡是要被枚举进离线自检的脚本，必须提供【不碰硬件】的 `--selftest`**；
⚠️ 做不到就**改名加 `_` 前缀**（⭐ 枚举器会跳过）。

📌 ⭐ **别靠"我记得它不该跑"** —— ⭐ 枚举器**不认记性**，⭐ 只认那个字面串。

### ⭐⭐ 屏上诊断的**判读表**（⭐ 再出问题照这个看）

| ⭐ 现象 | 🔴 指向 |
|---|---|
| `hmi.tx` 涨 + 屏变 | ✅ 全通 |
| ⭐ **`hmi.tx` 涨 + 屏不变** | 🔴 命令到了但**屏没应用**（⭐ 控件名/属性/颜色）**或没重绘** |
| ⭐ **`hmi.tx` 不涨** | 🔴 **固件没走到**（⭐ 查 `dirty` / 是否绕过了封装） |
| ⭐ **`hmi.rx` 不涨** | 🔴 屏 → ESP32 没通（⭐ 查接线 / 共地） |
| ⭐ **`get` 回值对 + 屏不变** | 🔴 **值对了但没重绘**（⭐ 试 `vis=0`→`1` 强制重绘，⭐ 见 `C139`） |
| ⭐ **读回只有 31 个字符** | ⚠️ **不是截断** —— 固件 RX 缓冲只有 **32 B** ⇒ ⭐ **回复分多行** ⇒ ⭐ 要**拼到 `FF FF FF`** |

### ⭐ 编译 / 烧录

```powershell
cd C:\Users\hokuu\Desktop\FPGA\FPGA2026-esp32\esp32\ble
.\build.ps1 -Action build
.\build.ps1 -Action flash -Port COM29      # ⚠️ 端口按 VID_303A 确认
```

⚠️ `build.ps1` 的 `-Action` 是**必填**参数（⭐ 不传会报 `MissingMandatoryParameter`）。
⚠️ ESP-IDF 在 `C:\Espressif`（⭐ EIM 安装），⭐ `build.ps1` 会自动激活。

### 曲谱灌流通路（2026-10-01 打通并真机验证）

**谱面从哪来**（🔴 头号误解：⛔ **不是** `.gp`）

```
Guitar Pro 导出 MIDI
   ↓  FPGA2026/tools/mid2evt.py --in <score.mid> --out-dir <dir>
events.hex   （每行一个 16 位十六进制 = 64 bit 事件字，无帧头）
   ↓  esp32/tools/send_frames_ble.py --hex <events.hex>
PC ──BLE──> ESP32 池 ──UART1──> FPGA
```

🔴 **⛔ 不要去找 `gp2evt.py`** —— 它已归档为
`tools/archive/gp2evt-过时-已改用MIDI方案.py`（⭐ 文件名自己写着"过时"）。
⚠️ 而 `files/20-代码/曲谱自动演奏分析.md` §九 仍写着「`gp2evt.py` 尚未创建」
⇒ ⭐ 那句**只对 `.gp` 路线成立**；⚠️ **MIDI 路线早就做完并跑过了**。

**现成的谱面**（在 FPGA2026 主仓库的 `build/` 下，⚠️ **未入库**）

| 文件 | 事件数 | tick 范围 | tempo 条数 |
|---|---|---|---|
| `build/score/regen/6.世界悲(已修订)/events.hex` | 9779 | 0..725760 | 1（在 tick 0） |
| `build/score/regen/夜洋风景/events.hex` | 11566 | 0..447360 | 2 |
| `build/score/regen/09_Conjurer/events.hex` | 11865 | 0..814080 | 7 |

⚠️ 池容量 **18204** 帧 ⇒ 三首都装得下（更长的谱面要分段灌，用 `--no-clear`）。

**灌谱三步**（⛔ 不能只做第 2 步）

1. ⭐ **`CMD 0x01` 清池** —— ⚠️ **必须**。帧流里的"复位序列"（4 帧全 `0xA5`）**不清池**：
   它只把固件的【本曲事件计数】清零（`ble_main.c:925-938`），且被丢弃、⛔ 到不了 FPGA。
   ⚠️ 实测：不清池连灌两首 ⇒ `pool` 200 → **9979**（追加，旧曲残留）。
2. ⭐ **灌 `events.hex`**：`python send_frames_ble.py --hex <f>`
   （⭐ 它**默认就会先发 `CMD 0x01`**，可用 `--no-clear` 关掉）
3. ⭐ **`CMD 0x03` 起播**

**真机验收判据**（⭐ 全部机器可验，⛔ 不需要人看屏）

| 判据 | 期望 |
|---|---|
| `ble_rx` 增量 | = 整包字节数（9×事件数 + 36 + 9） |
| `pool` | = 事件数（⚠️ 清池之后；⛔ 不是累加） |
| `tf` / `unk` / `ovf` / `mm` | 事件数 / 0 / 0 / 0 |
| `sent` | 单调涨到事件数（⭐ **中途不许有 ≥60 秒的平台**） |
| `run` | 结束时 = 0（自然放完） |
| 屏上 `t1` | `待机` → `就绪` → `播放中` → `播完` |

⭐ 一条命令拿全部：`python _score_play_probe.py --hex <f> --minutes 9`
（⭐ 它同时读 STAT 与屏上 `t1`/`t2`，并自动判"有没有长平台"。
⚠️ 串口只能有一个读者 —— 见 `U85`）

⭐⭐ **最强的一条（线上字节级）**：`python _uart1_wire_check.py --port COM31 --hex <f> --seconds 450`

把 USB-TTL 的 **RX 接 ESP32 的 `GPIO17`**（UART1 TX），PC 就当 FPGA 收包，
再与 `events.hex` **逐帧逐字节**比对。

⚠️ **为什么这条必须做**：`sent=11865` **只证明 `uart_write_bytes()` 返回了 9**，
⛔ **不证明线上那 9 个字节是对的**（同族 `L113`：判据锚在中间状态 ⇒ 下游缺陷在回归里不可见）。
🔴 而且位域刚修过 —— 不看线上字节就无法排除"发出去的是错的"。

📊 **实测（09_Conjurer，2026-10-01）**：
`106785 字节 = 11865 × 9`（一个不多一个不少）· 帧头非 `0xA5` **0 处** ·
**11865 帧逐字节一致**（⭐ 这也是位域修复在**线上字节层面**的非空洞性证明）。

⭐⭐ **由这条测试顺带确认的一个选项**：既然 ESP32 的 `GPIO17` 确实在按正确字节发帧，
那么 **ESP32 `GPIO17`(TX) → FPGA `J9` 的 `N26`（`D14` = `uart_rx`）** ＋
**ESP32 `GPIO18`(RX) ← FPGA `J9` 的 `N25`（`D15` = `uart_tx`）** ＋ 共地，
⇒ ⭐ **零 FPGA 改动**即可让 FPGA 收到（`constr/top.cst:364/366` 已绑好这两个脚，
`SCORE_UART_ENABLE = 1`，`uart_tx.v` 也已在 `top.v:946` 例化）。
⚠️ 代价：占掉 `J9` 的 USB-TTL 调试口（二选一）。
⚠️ 用户 2026-10-01 裁定的是「在 `PMOD0` 新开第二路」（两个口都留）——
⭐ 本条只是**把 A 方案的可行性从"物理上可行"提升到"ESP32 侧字节已实测正确"**，⛔ 不改变裁定。

**🔴 两个已修的真缺陷（⭐ 都会让真谱面放不出来）**

| # | 症状 | 根因与修法 |
|---|---|---|
| 1 | 🔴 **BLE 路径的位域是旧的** ⇒ FPGA 解出 `inc>>1`（低一个八度）、轴号被 `inc` 污染 | `send_frames_ble.py` / `screen_demo.py` 用的是 2026-09-22 修订【之前】的布局。⭐ 修法：位域收进 `score_word.py` 作**唯一定义处** |
| 2 | 🔴 **中段换速后喂水停住**（09_Conjurer 冻在 7445 达 **167 秒**，第 2 条 tempo 之后就基本放不出来） | `pool.c` 门控把【时长】与【位置】相加后比大小；换速重锚把位置拉回去 ⇒ 条件不可满足。⭐ 已修（见经验库 `C155`） |

### ⭐ 上位机（2026-10-12 新增）—— 三个网页 + 一个全量执行器

| 文件 | 是什么 |
|---|---|
| `esp32/tools/start_score_studio.bat` | **双击这个**：起本地服务（`127.0.0.1:8777`）并开浏览器 |
| `esp32/tools/score_studio.html` | 曲谱上位机：看谱 / 清池 / 上传 / 起播 / 实时状态 |
| `esp32/tools/upstream_studio.html` | 回传可视化：订阅 `0xABF2`，把上行帧画成钢琴卷帘，可导出 `.mid` |
| `esp32/tools/link_test.html` | 链路自检：六项一键跑（BLE / STAT / 下行 / 起播 / 上行 / 屏） |
| `esp32/tools/run_all_tests.py` | **全量顺序执行器**：离线 + 全部真机测试，出汇总表，退出码 = 失败项数 |
| `files/20-代码/上位机使用文档-20261012.md` | **使用文档**（怎么开、每步判据、故障对照表） |

⚠️ **为什么必须走 `.bat`**：Web Bluetooth / Web Serial 要求**安全上下文**，
`http://127.0.0.1` 是、`file://` **不是** ⇒ 直接双击 `.html` 蓝牙会被拒。

⭐⭐ **操作陷阱（实测两次）**：**网页与 Python 工具不能同时用。**
网页握着 BLE 时，板子停在「僵尸连接」（`mtu=517 | CONN` 但 `ble_rx=0`）⇒
**不广播** ⇒ 所有 Python 真机工具全部连不上，看起来像"板子死了"。
⭐ **关掉网页几秒后板子即恢复广播。** 用 `run_all_tests.py` 前务必先关网页。

⭐ **真机验证（2026-10-12，都是我自己驱动网页跑出来的）**：
- **发送链路**：连接 → 清池 → 上传 → 起播。判据：池 `0 → 111`、总数帧 `111`、
  `run=运行中`、已喂帧从 0 开始涨、卷帘游标在移动 ✓
- **接收链路**：PC 当 FPGA 灌 `GPIO18` 151 帧 / 2168 字节 ⇒ 网页收到
  **字节 2168 · 帧 151 · 音符 150 · 表同步 1 · 坏校验 0 · 未知 0 · 重新同步 0**，
  事件流解出 `C2/G2/F2/D2`（与灌入的 MIDI 36/43/41/38 逐个对得上）✓

**🔴 五个真缺陷 —— 都已找到根因并修复（⭐ 2026-10-12）**

| # | 症状 | 根因 | 修法 | 验证 |
|---|---|---|---|---|
| 1 | **起播后约 20 秒 BLE 掉线 + 板子重启** | ⭐ **`BTC_TASK` 栈溢出** —— 蓝牙主机任务的栈用的是 IDF 默认值 **3072 字节**，而起播时 GATT 读（STAT 轮询）＋ 通知 ＋ 池泵写 UART1 **三者同时进行**，调用链最深 ⇒ 撑爆 | `CONFIG_BT_BTC_TASK_STACK_SIZE` **3072 → 6144**、`CONFIG_BT_BTU_TASK_STACK_SIZE` **4352 → 6144**。⚠️ 必须改 **`sdkconfig.defaults`**（入库真源）**并同时改**本地 `sdkconfig` —— ⛔ 只改后者会在重新生成时被覆盖 | ✅ **修复前**第 19 秒崩；**修复后** 120 秒 / 轮询 72 次全程没断、播放自然放完，取证日志**零崩溃标记** |
| 2 | 重启后 BLE 能连上、但 GATT 服务不完整（`0xABF3 not found`） | ⭐ **同一个根因的下游症状** —— 崩溃重启后 BLE 栈处于异常态 | 修 #1 之后**未再复现** | ✅ 全量测试连续通过，含「读状态 0xABF4 八组齐全」 |
| 3 | **对账差 4~84 帧，且 `0xABF4` 里没有任何字段能解释差额** | 下行对齐环形缓冲（`ALIGN_BUF_CAP=1026 B`）**满了会截断**，丢掉的字节只累加到 `s_ble_rx_dropped` —— ⚠️ 这个计数**只出现在另一条日志分支**里，`0xABF4` 完全没有它 ⇒ 违反"会出错的容量必须看得见"（`K-106`） | `0xABF4` 的 `ble=` 组补 **`drop=%lu`**：`ble=rx%lu tx%lu fail=%lu drop=%lu mtu=%u conn=%d sub=%d`（⚠️ 格式串与参数顺序严格一致） | ✅ 新字段上线；对账等式**连续 4 次严格成立** |
| 4 | **`unk`（未知帧头）凭空增长**（5 轮循环后 +50，每轮 +10） | ⭐ **环形缓冲按"剩余字节数"截断 ⇒ 一帧被切成两半 ⇒ 后续字节整体前移 ⇒ 帧相位永久错乱** ⇒ 数据字节被当成帧头 | ⭐ 截断**按整帧对齐**（只写"能放下的整帧"），**不足一帧的尾巴跨调用留存**（静态残留 < 1 帧）；⚠️ 清池时一并丢掉残留（⛔ 否则两曲半帧会拼成假帧） | ✅ 5 轮循环 `unk` 增量 **0**（修复前每轮 +10） |
| 5 | 🔴 **屏上显示 `18704/200`**（用户实测报告：已收远超应到） | ⭐ **「本曲已收事件数」跨曲累加** —— 它**只在收到「复位帧」时清零**，而**「总数帧」才是声明"新曲子应到多少"的那个点**，到达时没清 ⇒ 客户端不反复发复位帧时，分子无限累加 | ⭐ `frame_parse_total()` 收到总数帧时一并清零（⭐ 谁声明边界谁负责归零）；`0xABF4` 的 `frame=` 组加 **`ev=%lu`** 暴露内部真值；⚠️ 显示层加钳制**仅作兜底**（⛔ 不是修法） | ✅ 灌 3 曲完整整包 ⇒ `ev` = **200/200/200**，屏上 `t2` = **`200/200`**；⭐ 非空洞性：撤掉清零 + 只声明一次总数 ⇒ `ev` = 200/**400**/**600** 精确复现 |

**⭐ 崩溃现场（取证抓到的原文，⛔ 不是推测）**

```
***ERROR*** A stack overflow in task BTC_TASK has been detected.
Backtrace: 0x40375dc5:0x3fcb3d50 0x40380a71:0x3fcb3d70 ... |<-CORRUPTED
ELF file SHA256: 37313d691
Rebooting...
rst:0xc (RTC_SW_CPU_RST),boot:0x2b (SPI_FAST_FLASH_BOOT)
```

⭐ **定性要点**：`rst:0xc (RTC_SW_CPU_RST)` = **软件复位** ⇒ 是**固件崩溃**，⛔ **不是掉电**。
⚠️ **负面证据也要记**：日志里**没有** `Brownout detector was triggered` ——
这条才把"供电不足"排掉（⛔ 没有它，排除就是猜的）。

⭐⭐ **一个根因，多个症状**：修掉栈溢出之后，此前那些**间歇性**失败
（`OSError 操作已被用户取消`、测试级联红、`0xABF3 not found`）**全都不见了**。
⇒ ⭐ 这正是"修根因 vs 改表象"的差别：改表象会留下这一串"偶尔抽风"。

**⭐ 取证方法（⛔ 可复用，别再踩）**
🔴 **⛔ 不要用"攒到最后再输出"的日志工具** —— 崩溃瞬间的证据会随进程一起丢。
✅ 用 `esp32/tools/_crash_capture.py`：**当场 flush + fsync 落盘**，每行都在崩溃前落地。
⭐ 经验编号：`C163`（固定时间崩溃先怀疑栈 + 取证当场落盘）、
`C164`（帧流截断必须整帧对齐）、`C165`（对账先怀疑读数时刻，看差值的**形状**）。

**⭐⭐ 对账等式（⭐ 排障时照这个算，⛔ 别再用"我发出去多少帧"）**

```
ESP32【收到】的帧 = 进池 + 溢出 + 未知 + 复位 + 截断丢
                    ^^^^ pool  ^^^^ ovf  ^^^^ unk  ^^^^ rst  ^^^^ ble.drop/9
```

⚠️ **⛔ 不要拿"我发出的帧数"当基准** —— BLE 的无响应写**没有投递保证**，
空口丢的帧 ESP32 根本没收到、自然不记账（⭐ 这是两个不同的基准）。
⚠️ 读 STAT 前**要等排空任务追平**（等 `ble_rx` 连续两次不变），
⛔ 不是拍一个固定 sleep（⭐ 实测固定 sleep 在慢机器上会偶发失败）。

**⭐⭐ 差值的【形状】比大小信息量大（⭐ 排障口诀）**

| 差值形状 | 含义 |
|---|---|
| **常数** | 系统性偏差（口径/配置错） |
| **某批大小的倍数** | **时序/追平问题**（读太早，⛔ 不是丢数据） |
| **随机小数** | 真的丢数据 |

⚠️ **一个已修正的误判（⭐ 教训）**：曾把日志里时间戳"倒退"
（`241001 → 178341`）当作重启证据。⭐ 那更可能是**日志环形缓冲先回放旧行、
再跟实时流**造成的假象 —— 本次 423 秒连续日志**时间戳单调递增、期间没重启**。
✅ **真正的判据是 `up`（uptime）归零**（实测：`9976418ms → ~180000ms` ⇒ 确实重启过一次）。

---

## 五、🔴 安全与纪律（⭐ 硬性，⛔ 不可协商）

| # | ⭐ 规则 |
|---|---|
| **1** | 🔴 **WS2812 指示灯必须保持关闭** —— `WS2812_ENABLE=0` + `WS2812_CLEAR_ON_BOOT=1`。⭐ 用户明确说「**安全第一**」「ws2812 好像有**锁存**，一定要确保关掉」。⭐ 固件**每次开机都强制清锁存**（⭐ 因为锁存值**能扛过重启**）。 |
| **2** | ⭐ **本地 commit 不限次数**；🔴 **push 必须先问用户**。 |
| **3** | ⭐ push 前**必须把本周期所有提交压成 1 个**（⭐ 先 `tag pre-squash/<日期>` + `git bundle` 到仓库外）。⛔ **禁止 `push --tags` / `push --all`**。<br>🔴🔴 **2026-10-01 修正（⭐ 补一条硬判据）：⭐ 打完 tag 必须核对 `git tag --points-at HEAD` 非空** —— ⚠️ **⛔ 不是"`git tag` 命令没报错"**。⭐ 原因：🔴 **ref/tag 是【22 个 worktree 共享】的命名空间**（⭐ 见文件头）⇒ `pre-squash/<日期>` 很可能**已被另一条线占用** ⇒ ⚠️ 而"存在就跳过"的守卫会**静默跳过**，⭐ 结果 **HEAD 根本没被钉住，脚本却继续往下走**（⭐ 实测踩过：`pre-squash/2026-10-01` 已被占用，⭐ 最终改用 `pre-squash/2026-10-01c`）。 |
| **4** | ⭐ **改工程 / 写总结前先 `git fetch`** 看远端有没有新提交。⚠️ **远端领先时 ⛔ 不要直接 `reset --soft`**（⭐ 会把队友的文件从工作区抹掉 —— ⭐ **本会话真出过这个事故**）。 |
| **5** | ⭐ **`esp32/.gitignore` 里有 `*.mid`** —— ⭐ 生成的 MIDI ⛔ 不入库。 |

---

## 六、⭐ 经验库（⭐ 位置 `C:\Users\hokuu\Desktop\经验`）

| ⭐ 规则 | ⭐ 内容 |
|---|---|
| ⭐ 开工前 | ⭐ 先读 `README.md` 的**索引**（⭐ 血泪索引按**症状**查） |
| ⭐ 写入 | ⭐ **UTF-8 无 BOM**，⭐ 写完**回读首字节**确认不是 `EF BB BF` |
| ⭐ 分流 | ⭐ 逻辑→`L##` · 工具→`U##` · 跨领域→`C##` · 过程→`TROUBLESHOOTING.md` |
| ⭐ **push 阈值** | ⭐ **满 10 条新经验自动 push**（⭐ 这是 push 纪律的**唯一例外**）；⛔ **不足 10 条只 commit** |
| 🔴 **禁止** | ⛔ `git add -A` / `git add .`（⭐ 公开仓库，⭐ 历史上误推过含**订单号/单价**的 `备料.md`，⭐ **无法从历史撤回**） |

⚠️ **编号会撞车**：⭐ 有**另一条线在同时录入** ⇒ ⭐ 录入前先查当前最大编号，
⭐ **取最大值 +1**，⭐ 写完再**核对有没有重号**。
⚠️ **`README.md` 的计数行**（`C01~C###`）⭐ 也要同步更新。

---

## 六·五、🔴 2026-10-14 本轮修的**四组**（⭐ 都已回归 + 双向验证）

> ⚠️ 这四组都是**用户实测报出来的**，不是我自己找的。
> ⭐ 每组都有回归判据，且**双向验证过**（改回旧写法必须变红）——
> ⛔ 不是"我打了补丁就当修好了"。

| # | 用户报的现象 | 🔴 真根因（⭐ 都在上游） | ⭐ 修法 | 回归判据 |
|---|---|---|---|---|
| **1** | 🔴 BLE「服务发现只有 4 个」`0xABF*` | Windows **按 MAC 缓存 GATT 表**（⛔ 不是按设备名）⇒ 固定地址第二次连就命中缓存，服务表是上一次那版 | 上电时 `esp_random()` 生成**随机地址**（`ble_main.c: ble_gen_rand_addr`），adv 用 raw 数据 | `stat_read.py --scan-timeout 25` ⇒ `0xABF*` = 4 |
| **2** | 🔴 「同时按下的和弦没被识别」 | FPGA `note_manager.v:870`：**每个 `(axis, src)` 同时只有 1 个在响**的 voice（同源 `note_on` 被 `same_hit` 命中 ⇒ 复用）。而我方把 Guitar I/II/III **全合并到 axis 0** ⇒ 6 音和弦只剩 1 个 | **配对成段 + 贪心分配 axis**（重叠的必须分开，⛔ 不重叠才共用） | `_chord_axis_check.js` 10 项；实测真同时 **9 → 1** |
| **3** | 🔴 「168 BPM 听着像 120」 | 两条叠一起：①**tempo 轨没音符** ⇒ `parseMidi` 按"有无音符"过滤轨时**整个丢掉**；②即便没丢也只发 tick 0 那一帧 ⇒ 中段变速全丢 | parse 阶段汇总**全局 `allTempos`**（⛔ 不受轨过滤影响）；**所有** tempo 都发 `kind=2` | `_midi_parse_check.js`（含"3 tempo ⇒ 3 个 kind=2"）；实测 `09_Conjurer.mid` 7 个全发出 |
| **4** | 🔴 一键上传卡在 BLE、没进度条；`axisSwatchColor is not defined`；统计面板全是 `-` | ① `gattSerial` **自嵌套**：`readStat` 内部又入队 ⇒ 自己等自己；② 改图例引用 `axisSwatchColor` **却漏写定义** ⇒ `draw()` 每帧抛错 ⇒ 面板/进度条都停 | ① `sendCmd`/`readStat` 改为**叶子函数**（⛔ 不再自己入队），入队责任交给调用方；加 **15 s 看门狗**；② 补函数定义 | `_deadlock_check.js` 6 项；`_undef_check.js` 6 项 |

### 6.5.1 FPGA 侧**不需要**配合的部分

⭐ 第 2/3 组纯**我方**问题 ⇒ ⛔ 不指望他们改。
⭐ 第 4 组也纯我方。

### 6.5.2 三条等 FPGA 侧的口径

| # | 事项 | 状态 |
|---|---|---|
| A | 🔴 **同时敲多个鼓**会互相顶掉（用户谱子 **568 次**同 tick 敲 ≥2 件）—— 与第 2 组**同一个** `same_hit` 机理 | 📩 已追问（`ESP32侧追问-同时敲多个鼓与same_hit-20261014.md`），三选一请他们定 |
| B | ⚠️ **XOR 校验覆盖范围**：他们文档写 `[1..12]`，我方实现**含 `0xA5`**（`[0..12]`）。他们说"以我方为准、他们改" | ⏳ **RTL 尚未落实** ⇒ 联调若报"坏校验"就是这个 |
| C | ⚠️ **14 B 实时上行帧**：他们模块已落地（30 判据全绿）+ `seq_arb` 鼓来源已改 | ⏳ **含改动的位流未出** ⇒ 真机联调未做 |

### 6.5.3 ⭐ 一条不值钱的教训（本轮栽了 4 次）

🔴 **补丁没落盘 / 没确认 = 没修**。本轮四次：
① `[IO.File]::WriteAllText` 登记新工具从不回读；② `_p33` assert 失败却没注意 ⇒
"全发 tempo"那步**实际没生效**；③ 补丁按文本匹配失败 ⇒ 函数体完全没被换；
④ 白名单放循环里 ⇒ 对最终退出码无效。

⭐ **现在一律**：⭐ **改完立即回读确认** + ⭐ **行号替换代替文本匹配** +
⭐ **每条改动点逐条确认** + ⭐ **判据必须双向验证**（0.11 §C83）。

## 六·六、⭐⭐ 2026-10-15 实机结果（⭐ 上板实测，⛔ 不是仿真）

> 按 0.17：实机测完就落文档。本节写**能用的 / 不能用的 / 与文档不一致的**。

### ① 当前状况（⭐ 判据都是实机日志）

| 环节 | 状态 | 实机判据 |
|---|---|---|
| **PC → BLE → ESP32 灌谱** | ✅ **零丢失** | `ble_rx=170460`（= 应发字节）；`pool=18935`（= 应到帧） |
| **网页帧数核对** | ✅ 可用 | `✅ 帧数核对通过：15681 / 15681 帧全部到齐` |
| **起播出声** | ✅ 能放 | 用户确认"放出来了"；`sent=6728` 说明确实喂给了 FPGA |
| **池溢出** | ✅ 无 | `ovf=0`（池 2 MB / 233016 帧） |
| **崩溃 / 复位** | ✅ 无 | 串口日志无 `Backtrace` / `rst:` |
| **速度** | ⏳ **7.1 KB/s** | 141 KB 用 19.4 s；分段实测 **2.8 ~ 16.6 KB/s 波动** |

### ② 🔴 今天修的（⭐ 每条都有实机证据，⛔ 不是推测）

| # | 问题 | 根因 | 修法 |
|---|---|---|---|
| 1 | 灌谱慢到 1.1 KB/s | 我把灌谱改成**带确认写**，每包等一个 ATT 往返，ESP32 忙时 436 ms/包 | 改回无确认写 + 用 notify 做流控 |
| 2 | **丢 36% 帧** | **窗口 64 KB 太大** ⇒ 开头在途=0 时不拦 ⇒ 一口气灌爆控制器 RX 缓冲 | 窗口 64 KB → **8 KB**，notify 1500 → **100 ms**（⭐ 两参数互相依赖，必须一起改） |
| 3 | 起播要等十几秒 | `pollOnce` 在 notify 已订阅时**仍主动读**，读挂住 ⇒ 起播命令堵在队列后面 | 订阅成功时 `pollOnce` **直接 return** |
| 4 | 报"丢 4.5%" | 核对跑太早 —— 最后一包**还在途**（860×9 = 7.7 KB ≈ 窗口 8 KB） | 核对前**等在途排空**（`fcSent-fcAcked` 归零） |
| 5 | 浏览器蓝牙栈卡死 | 看门狗丢弃 Promise 但**无法取消**已发出的 GATT 操作 | 轮询不设超时 + 不堆积 + 卡死检测 |
| 6 | 上传后立刻读 STAT 卡死 | 写最后一包就 `readValue`，而那正是 ESP32 最忙时刻 | 挂标记，复用轮询那次读 |
| 7 | 断连时抛看不懂的 TypeError | 断连把 `chRecv` 置 null，上传循环还在用 | 发送出口加断连守卫，抛可读错误 |

### ③ ⭐ 两条最贵的教训（⭐ 下个会话必看）

**🔴 教训一：`ble=rxN` 是【自开机累计】，⛔ 不是"本次已收"。**
实测症状：`已发 75 KB · ESP32 实收 240 KB · 在途 -166 KB` —— 实收**比已发还多**、在途算成**负数**。
⇒ `在途 > 窗口` 永远不成立 ⇒ **流控彻底失效** ⇒ 全速冲 ⇒ 丢帧。
⇒ ⭐ 这解释了那个怪现象：**一次会话里"前面慢而能放、后面快而放不了"**。
⭐ 修法：本次上传记**基线**，只用增量（`fcAcked = bleRx - fcAckedBase`）。

**🔴 教训二：流控的"窗口大小"本身就是丢帧的成因。**
⭐ 关键不在"丢了多少"，而在**什么时候丢**：
```
已发 75 KB  -> 实收 11 KB    （这一步丢了 85%！）
已发 150 KB -> 实收 96 KB    （累计 36%）
```
⇒ 开头在途=0 时不拦 ⇒ **一口气把整个窗口灌进链路** ⇒ 控制器 RX 缓冲爆。
⇒ ⭐ 所以"窗口大"⛔ 不是"能收多快"的上限，而是**突发量**。

### ④ ⚠️ 与旧文档/旧结论不一致的（⭐ 已当场改口径）

| 旧说法 | 实测 | 处置 |
|---|---|---|
| "ESP32 只能收 4~7 KB/s" | ⚠️ 那是在**累计值 bug** 下测的 ⇒ **无效** | 已作废；真值见上表 |
| "连接间隔太长是主因" | ❌ 实测 `interval=24 (30 ms)` / `12 (15 ms)`，**本来就快** | 该假设**已排除**（固件新加了日志，⛔ 不再靠猜） |
| 池容量 160 KB 够用 | ❌ 212 KB 的谱装不下 ⇒ 溢出 | 已改 **2 MB**（PSRAM 有 8 MB） |

### ⑤ ⏳ 仍未解决

1. **速度只有 7.1 KB/s**（分段 2.8~16.6 KB/s 波动）
   ⇒ ⭐ 换算约 **11 次写/秒**（480 B / ~96 ms）⇒ **主机每次写约 90 ms**，异常慢。
   **已排除**：连接间隔、空气时间、`ble_buf_push`、`hmi_set_state`（无锁）。
   **待查**：① Bluedroid 主机任务还缓冲慢；② `task_drain`（优先级 9）往 PSRAM 池搬运慢；
   ③ 掉速时段（3 KB/s）时 ESP32 在干什么（HMI？notify？池搬运？）。
2. **偶发断连**（曾在上传 31 秒时出现一次；之后多次复现不出）—— 待复现时抓串口。

## 七、⏳ 未决项（⭐ 明确记录，⛔ 不假装已修）

⚠️ **2026-10-12 重排**：原文把「**已裁定不做**」「**未裁定**」「**阻塞在外部**」
「**已完成**」四类混在一张表里 ⇒ 🔴 **下个会话会把它读成"漏修的 bug"**
（⭐ 本轮实测：我自己就先把它当成漏修的缺陷，查到 §P3 才发现是**用户早先裁定不做**）。
⇒ ⭐ **必须按【能不能推进】分表**，⛔ 不要按"发现顺序"堆在一起。

### 7.1 ⛔ 已裁定「不做」—— ⚠️ 是**设计决定**，⛔ 不是漏修的 bug

> 🔴 **读到这里请停手**：下面两项**不要**当成缺陷去"修"。
> ⭐ 它们的代码**故意留着**（`hmi.h` 的枚举 + `hmi.c` 的字符串映射），
> 是为了让**语义定义**留在原处；⛔ **删了反而丢信息**。

| # | 项 | 裁定 | 现状（⭐ 已核实） |
|---|---|---|---|
| **1** | `HMI_ST_UNDERRUN`（屏上「供数不足」） | ⚠️ **用户裁定「先不做」** | ✅ 核实：全固件 `hmi_set_state()` **从没被传过** `HMI_ST_UNDERRUN` ⇒ 它是**死状态**，屏上永不亮 |
| **2** | `t4`（缓冲区水位） | ⚠️ **不做**（屏 320×240 位置不够） | ✅ 核实：`hmi.c` 里 `#if 0` 关着 |

⚠️ **第 1 项若要真做，前置条件**（⭐ 记下来，免得下次重新调研）：
- ⭐ **语义已定**：⭐ **观察窗口从【已起播】算起**（`ESP32通路总体架构-20260922.md:224`、`:357`）
  —— ⚠️ 起播前 `play_seq` 不消费 ⇒ 水位为 0 **不代表故障**
  ⇒ ⛔ **不能从"发送端开始发"算**，否则"灌完了人还没按键"会被**误判成 underrun**
- 🔴 **数据源还缺**：FPGA 侧有 `play_seq.evt_underrun_o`，但
  ⭐ **上行帧格式里没有 underrun 字段**（`esp32/tools/evt2midi/frame_format.py` 只有
  note_on / note_off / calib / looper / tablesync）
  ⇒ 🔴 **要真做，得先有【underrun 的上行字段】** ——
⚠️ v1.1 的帧类型里**没有** underrun（只有 note_on/note_off/calib/looper/
`transport_start`/tablesync）⇒ ⭐ **仍缺数据源**，需要向 FPGA 侧再提一次
（⭐ ⛔ 不是"等格式冻结"—— 格式 2026-10-01 就已给出，见 §7.3）

### 7.2 ⚠️ 待裁定 / 本轮在办

| # | 项 | 状态 |
|---|---|---|
| **3** | `LINK_LOST` 后的**恢复** | ✅ **2026-10-12 用户裁定：重连成功 ⇒ 屏上显示「就绪」**（⭐ 已实现，见 §7.2.1） |

#### 7.2.1 `LINK_LOST` 恢复的实现口径（⭐ 2026-10-12 新增）

| 项 | 内容 |
|---|---|
| **触发点** | `ESP_GATTS_CONNECT_EVT`（`ble_main.c`，与 `hmi_set_bt_connected(true)` 同一处） |
| **迁移条件** | ⭐ **仅当**当前状态 == `HMI_ST_LINK_LOST` 时才迁移 |
| **目标状态** | `HMI_ST_READY`（屏上「就绪」） |
| ⚠️ **为什么用 `READY` 而⛔ 不是 `IDLE`** | ⭐ `IDLE` 的语义是「**池是空的、什么都没装**」；<br>⚠️ 重连时池里**往往还留着上一曲的谱** ⇒ 说成「待机」会**误导人去按起播**。<br>⭐ `READY` 的语义是「**有谱、可以起播**」⇒ 与重连时的真实情况一致 |
| ⚠️ **为什么必须带条件** | ⛔ 否则「播放中断了一下又连上」会被**误拉回就绪** ⇒ 🔴 抹掉「播放中」这个真实状态（同族 `C141`：条件要看全，⛔ 别只认一个信号） |
| **判据** | ⭐ `hmi_states_check.py` 的 **`L4_RECOVER`** —— 断开 → 重连 → 读 `t1` **必须 == `就绪`** |

🔴 **它当初为什么没被测出来**（⭐ 教训，⭐ 比缺陷本身值钱）：
原判据**只验了「断开 ⇒ 断链」**，注释里还白纸黑字写着
「⚠️ 重连本身不会改状态」⇒ ⭐ **把"重连后"的值当成同一个结论**。
⇒ 🔴 **"重连后停在断链"这件事从头到尾没有任何判据看着**，做没做都测不出来。
📌 同族 **`C166`**（多防线互相掩盖）+ **`C167`**（谁声明边界谁负责）：
⭐ **一条判据只能代表一个行为；两个相反的行为必须各自有判据。**

### 7.3 🔴 阻塞在**外部**（⭐ 我方能做的已做完）

> 🔴🔴 **2026-10-12 重大更正：这一节原来的两条【全是错的】。**
>
> 原文写「**FPGA 侧未回函**」「**上行帧格式未冻结，等 FPGA 侧**」——
> ⚠️ **实际上 FPGA 侧 2026-10-01 就答复了，而且不止一份，共 5 份。**
>
> **为什么一直没看到**：他们把回复写在**主 worktree** 「FPGA2026/files/20-代码/」（历史引用，当前未收录），
> 而我方一直按 「FPGA2026-esp32/files/20-代码/」（历史引用，当前未收录） 找 ——
> ⚠️ 两个 worktree **是同一个仓库，但 `files/` 的内容不同**，
> 且**没有任何机制把回复同步过来** => 我方**空了 11 天**。
>
> ⭐ **教训（⭐ 这条比结论值钱）**：
> **"对方没回复"这个结论，必须先证明【找过所有可能的位置】。**
> ⚠️ 我当时的依据只是"当前 worktree 里没有" ——
> 🔴 那是**把"我没找到"当成了"它不存在"**（⭐ 同族 `C113`：错得看不出来，
> 只不过错的是"我的搜索范围"而不是"数据"）。
> ⭐ 正确做法：⭐ **先 `git worktree list` 列出所有 worktree，再逐个搜**，
> ⛔ 不要只在当前目录里找一遍就下结论。
>
> **已做**：5 份全部同步进本 worktree（哈希逐份核对），
> 并写了回函 `ESP32侧答复-FPGA上行帧v1.1-20261012.md`。

| # | 项 | 状态 | 说明 |
|---|---|---|---|
| **4** | FPGA 侧回函 | ✅ **早已回复**（10-01，5 份） | ⭐ 三条全部采纳：① 校验字节**必须有** ② 坏帧**必须记账**，⚠️ 且**计数必须饱和**（回绕会把"丢 256 次"读成"丢 0 次"）③ 校验驱动重同步 —— 但**不把扫帧头当平时的同步手段** |
| **5** | 上行帧格式 | ✅ **v1.1 已给出并已实现** | ⭐ 我方按它改完 `frame_format.py`（见下方 7.3.1） |

#### 7.3.1 上行帧格式 v1.1（⭐ 2026-10-12 已实现）

⭐ **权威依据**：`files/20-代码/FPGA侧答复-ESP32再回函-20261001.md` **§四**

🔴 **⚠️ 有两份都叫 v1.1，字段安排不同，必须以【14:52 那份】为准**：

| 文件 | 时间 | `0x05` 叫什么 | `[8..11]` |
|---|---|---|---|
| `FPGA侧回应-ESP32再回函` | 00:45 | `PLAY_START` | 仍是 `phase_inc`；`[7..10]` 放 `score_tick0` |
| `FPGA侧答复-ESP32再回函` | **14:52** | `transport_start` | **`ppqn`** |

⭐ **判定依据**：14:52 那份 §四 标题明写「在你 §三 基础上改 3 处」⇒ 它是**修订版**，
**显式取代**了 00:45 的字段安排。（⭐ 已在回函里请对方确认这个判定。）

```
[0]     0xA5   帧头          （与 ASCII 流天然不相交 —— ASCII 全 <= 0x7F）
[1]     类型    0x01 note_on / 0x02 note_off / 0x03 calib / 0x04 looper
                0x05 transport_start（v1.1 新增）/ 0x10 表同步
[2]     seq     8 位（只用于【短窗口】丢帧；750 ev/s 时 0.34 s 就回绕）
[3..6]  tick    32 位自由运行（Δt = (t2-t1) mod 2^32）
[7]     axis    0..15（0x05 类型填 0）
[8..11] phase_inc 32 位 —— ⚠️ 0x05 类型时【改放 ppqn】
[12]    vel     8 位（0x05 类型填 0）
[13]    校验    8 位（XOR）
帧长 = 14 B（⛔ 不变）· 表同步 0x10 = 68 B
```

⚠️ **必须记住的坑（⭐ 本轮实测踩到）**：
`0x05` 的 `[8..11]` 是 `ppqn` ⛔ **不是** `phase_inc`
⇒ ⭐ **解析器必须在"取 phase_inc"【之前】按类型分流**，
⛔ 否则遇到 `0x05` 会直接 `KeyError` 崩掉。

⭐ **`ppqn = 960`**（`beat_gen` 定义；反证 `rtl/w3b/drum_gen.v:82` 的
`TICKS_PER_STEP = 240 = PPQN/4`）。有了它 PC 侧才能算
`bar = tick / (ppqn × 拍号)`；⛔ 没有它就只能算相对间隔。

⭐ **判据**（`esp32/tools/evt2midi/frame_format.py` 与 `evt2midi.py` 的 `--selftest`）：
白名单恰为 6 类 · `0x05` 帧长 = 14 · `ppqn` 往返 = 960 ·
`ppqn=0` 回退但**如实计数** · **饱和计数**（反证：普通加法会回绕成 0）·
重同步只认「帧头 + 类型 + 校验」三条 · 含 `0x05` 的流**不许崩** ·
锚点**不影响** MIDI 输出（加/不加锚点，MIDI 字节逐字节一致）。

### 7.4 ✅ 已完成（⭐ 留档，⛔ 不要再当未决项）

| # | 项 | 结果 |
|---|---|---|
| **6** | 本地领先远端未推 | ✅ **2026-10-12 已推**：`2d545b8..c0c2a78  feat/s3-ble -> feat/s3-ble`，⭐ 领先/落后 = **0 / 0**<br>⚠️ **数字会变** ⇒ ⭐ **一律以 `git status -sb` 的 `ahead N` 为准，⛔ 不写死**（⭐ 原文写死过「21 个」⇒ 已作废） |

---

## 八、⭐⭐ 下一步目标（⭐ 按优先级，⭐ 带判据）

### 🥇 P0 —— **push**（⭐ 等用户一句话）

⭐ **本地领先远端若干提交待推**（🔴🔴 **2026-10-01 修正**：⚠️ 原文写死「21 个」⇒ ⭐ 实测 `ahead 22`；⭐ **以 `git status -sb` 为准**）。⭐ 流程：⭐ 先 `tag pre-squash/2026-10-01` + `git bundle` 到仓库外
⇒ ⭐ 把「待压清单 + 拟好的压缩 message」给用户看 ⇒ ⭐ 同意后 `reset --soft` + 单提交 + `push origin feat/s3-ble`。

### 7.5 ⚠️ 新发现：上行的【9 B 回传帧】与 v1.1 的 14 B 帧【不是一回事】

⭐ **来源**：FPGA 侧 2026-10-12 回复 §四（他们【主动】报的，⭐ 不是我们查出来的）。

### 7.6 🔴🔴 BLE「服务发现只有 4 个」的根因（2026-10-14 已修）

⚠️ **这条务必先读** —— 它的症状**看起来像"链路不通"，实际是 PC 侧的缓存**，
⭐ 不知道这一点会去查 RTL / 查固件，白费几小时。

#### 症状

PC 连上板子后，**只能发现 4 个 GATT 强制特征**
（`2a05` 服务变更 / `2a00` 设备名 / `2a01` 外观 / `2aa6` 中央地址解析），
**`0xABF1`~`0xABF4` 一个都没有** ⇒ `BleakCharacteristicNotFoundError`（`0xABF3 not found`）。

#### 根因

**Windows 按 MAC 地址缓存 GATT 服务表**，认定"这个设备只有 4 个服务"，
⇒ **根本不发起服务发现**。

#### 判据链（⭐ 这条链比结论值钱）

| # | 证据 | 说明 |
|---|---|---|
| 1 | 板子日志全部正常 | `attr table created OK` + 句柄 40/42/44/47/49 + `service started` |
| 2 | 复位 / 重烧固件无效 | ⛔ 排除"固件状态坏" |
| 3 | **改设备名无效** | ⚠️ 能扫到了，但服务表还是 4 个 ⇒ **缓存键是 MAC，不是名字** |
| 4 | 强制 UNCACHED 无效 | `winrt={"use_cached_services": False}` 仍是 4 个 |
| 5 | 广播加服务 UUID 无效 | 广播侧已正确宣告 `0xABF0`，连上仍 4 个 |
| **6** | ⭐⭐ **板子收到的 ATT 请求 = 0 条** | 🔴 **最反直觉、也最关键的一条**：客户端**压根没问** |
| **7** | ⭐ **对照实验：同一台 PC 连另一个 BLE 设备** | ✅ **能正常发现它的自定义服务（`fe55`）** ⇒ ⛔ 排除"PC 无能" |
| 8 | 发 Service Changed 指示返回 `ESP_OK` | 但服务表没变 |

#### 修法

广播地址由**出厂 public** 改为**随机静态**：

```
94:A9:90:2D:A6:62   →   C2:AA:20:26:00:01
```
· `.own_addr_type` = `BLE_ADDR_TYPE_RANDOM` + `esp_ble_gap_set_rand_addr()`
· 用**固定值**（重启后不变，便于日志比对）
· ⚠️ 若将来**又要清缓存**：⭐ **改这个地址即可**，⛔ 不用动注册表（也没权限）

**验证**：`0xABF*` 从 **0 个 → 4 个** ✅

#### 顺带修的一处

`CONFIG_BT_GATTS_SEND_SERVICE_CHANGE_MODE` 由 `AUTO` → `MANUAL`
（否则 `esp_ble_gatts_send_service_change_indication()` 被协议栈拒绝，
日志原文：*"can't send service change indication manually,
please configure the option through menuconfig"*）。
⭐ 保留它的价值：**将来改 GATT 结构时客户端能自动重新发现**。

#### ⭐ 教训

1. **"板子说成功" ≠ "对端收到的是对的"** —— 必须各自有判据。
2. **BLE 调试时，"对端问了什么"比"我发了什么"更有信息量**
   （这次的突破口就是"ATT 请求 0 条"）。
3. **改名字绕不过 MAC 缓存** —— 排查时要先问"缓存键到底是什么"。

---

### 7.7 ⭐ 不用 CH340 也能验 UART1 发送路径（2026-10-14 新增）

⚠️ **用途**：CH340 没接 / 接错时，**仍然能证明"ESP32 的 UART1 出口是好的"**，
⛔ 不必卡在"线没接就没法测"。

**方法**：BLE 灌谱 → 起播 → 轮询 `0xABF4` 的 `sent`（= UART1 **实际发出**的帧数）。

| 时刻 | `sent` | 说明 |
|---|---|---|
| 起播后 0~6 秒 | `0` | ⭐ **还在提前量内**（`play` 从 3776 涨到 14720，`lead=20000`）|
| **约 8 秒** | **`2`** | ⭐ **`play=20249 > t0+lead=40019`？** —— 见下 |
| 10 秒 | `24` | 正常推进 |
| 12 秒 | `32` | 正常推进 |

⭐ **判据**：`sent` **从 0 开始稳步增长** ⇒ UART1 发送路径正常。
⚠️ 而"起播后前 ~10 秒 `sent` 一直是 0"是**正确的**（提前量），
⛔ **不要误判成"没发出去"**。

📌 **这同时验证了新加的播放位置字段**（`play`/`t0`/`lead`）：
```
第 8 秒：play=20249  t0=20019  lead=20000
heard = 20249 − 20019 − 20000 = 230   ← 刚出声，值很小 ✓ 与"sent 刚开始涨"吻合
```

🔴 **它证明不了什么**（⭐ 边界要写清）：
**线上字节是否正确** —— 那必须有真 FPGA 或 CH340 在另一端。
⇒ 所以 `_uart1_wire_check.py` **仍然不可替代**，
本方法只是**在没接线时缩小怀疑范围**（把"ESP32 侧"和"接线"分开）。

---

### 7.8 ⭐ 当前真机验收状态（2026-10-14，含稳定性证据）

#### 全量连续 3 轮，结果【零抖动】

```
第 1 轮：通过 13 · 失败 2 · 退出码 2
第 2 轮：通过 13 · 失败 2 · 退出码 2
第 3 轮：通过 13 · 失败 2 · 退出码 2
```

⭐ **三轮数字完全一致** ⇒ 失败项**恒定**，⛔ 不是偶发。

#### 通过的 13 项

| 项 | 判据 |
|---|---|
| 离线全量自检 | 28 个工具，649 项 OK，0 项 RED |
| 上位机离线自检 | 全部通过 |
| 池算术校验 | 全部通过 |
| MIDI 回传端到端（离线） | 全部通过 |
| 网页 JS 语法检查 | 全部通过 |
| 读状态 0xABF4 | 八组齐全 |
| 端到端下行（灌 N 事件） | `sent=200` + 计数器增量全对 |
| 命令与上行回归 | ①~⑤ CMD 命令集全通过 |
| UART1 发送路径（仅 BLE） | `sent` 稳步增长 |
| 屏状态机 / 屏曲名 | 全部正确 |
| 异常路径 / 循环压力 | 全部通过 |

#### ⚠️ 失败的 2 项（🔴 均为**物理接线**，⛔ 非代码）

| 项 | 症状 | 为什么必须外部对端 |
|---|---|---|
| 下行线上字节级校验 | `前 0 帧` | 验的是 **UART1 线上字节**，要把 ESP32 发出的与灌进去的**逐字节比对** |
| 上行闭环逐字节校验 | `前 0 帧` | 要把字节**从外部**灌进 `GPIO18` 再收回 |

🔴 **这两项⛔ 不可能改走 BLE**（它们验的就是 UART1 线上的字节）。
📌 **接线要求**：`ESP32 GPIO17(TX) → CH340 RXD` · `CH340 TXD → ESP32 GPIO18(RX)` ·
**`GND 必须共地`**。
⭐ 症状是"**一个字节都没收到**"（⛔ 不是"字节不匹配"）⇒ 明确指向**没接 / 没共地**。

#### ⭐ "ESP32 侧是好的"有【4 条独立判据】

⭐ 即使这 2 项因缺硬件红着，也⛔ 不等于 ESP32 侧有问题：

1. **UART1 发送路径（仅 BLE）** —— `sent` 从 0 稳步增长到 56
2. **e2e 的 `sent`** —— `200`（期望 200），⛔ 不需要 CH340
3. **regress_live 的 ①~⑤** —— CMD 命令集全通过（全走 BLE）
4. **BLE 相关项连续 3 轮全绿** —— 12/12（读状态/发送路径/屏状态机/异常路径）

⇒ ⭐ **结论：ESP32 侧全部就绪；只差那两根线。**

---

| 侧 | 上行帧长 | 出处 |
|---|---|---|
| 协议 v1.1（已冻结） | **14 B** | `FPGA侧答复-ESP32再回函-20261001.md` §四 |
| 🔴 FPGA 侧**已实现**的"录制回传" | 🔴 **9 B**（`0xA5` + 8 B） | `rtl/w3c/rec_dump.v`（2026-10-11 新加） |

⭐⭐ **关键认知：它们不只是"长度不同"，而是【帧结构不同】**：

```
9B 帧： [0]=0xA5  [1..8] = 8 字节数据
14B 帧：[0]=0xA5  [1]=类型 [2]=seq ...
                 ^^^^^^^^ 同一个位置，放的东西不一样
```

⇒ 🔴 **9B 帧的 `[1]` 是【数据】，而 14B 帧的 `[1]` 是【类型】**。
⇒ ⭐ 所以它不是"14 B 的短版本"，**必须能被区分**，
⛔ 否则解析器会把 9B 的第 2 字节当类型读（⭐ 读到垃圾）。

**我方当前行为**（✅ 已实测）：**安全拒收** ——
`frame_len_known(0x00) = None` ⇒ `parse_frame` 抛「未知类型 0x00（不猜长度，拒收）」。

**我方建议**（⭐ 已回函）：**加一个独立的类型码**，⛔ 不要改回传的帧长。
理由：语义本来就不同（**批量导出** vs **单个事件**），
且加类型码**不破坏定长状态机结构**（两端各加一个白名单项即可）。

⚠️ **待 FPGA 侧回 4 项**：① 类型码取值 ② 帧长 ③ `[1..8]` 的字段划分
④ ⚠️ 要不要补**校验字节**（⭐ 他们 §六 说 9B 帧**没有校验** ——
若它要进我方解析器，那会成为整条上行里**唯一"坏帧无法发现"**的一段）。

📌 **不阻塞我方**：⛔ 我方现在不需要改任何东西；等他们定了类型码再动
（`frame_format.py` 是**唯一定义处** ⇒ 改一处 + 自检会立刻指出哪条判据红了）。

### 🥈 P1 —— **接 FPGA 端到端**（⭐ 现在**唯一**的大块缺口）

| ⭐ 子任务 | ⭐ 判据 | ⭐ 阻塞? |
|---|---|---|
| ⭐ **`G21`/`G22` 引脚分配** | ✅ **已完成** | `constr/top.cst:482/484`（`esp_uart_tx_o`=G21 · `esp_uart_rx_i`=G22 · LVCMOS33 · G22 上拉） |
| ⭐ **ESP32 → FPGA 实音验证** | ✅✅ **2026-10-14 已贯通** —— FPGA 侧 `上板问题清单-20261013.md` **撤销 P4**，依据是**用户现场确认**「esp32 能发送曲谱然后发音，不用排查这个了」。<br>他们给出的完整链路：`ESP32 → G22 → u_uart_rx_esp → u_evt_uart_rx(0xA5 9字节帧) → u_evt_buf → u_play_seq → seq_arb → note_manager`<br>⭐ **这是我方第一次拿到「声音」这个终点判据**（此前只验到「UART1 出口的字节与灌进去的一致」）。 | ✅ **已通** |
| ⭐ **FPGA 回传音乐事件** | ⭐ `rec_upstream.py` 录到的字节 ⇒ `evt2midi.py` 转出**能播放的 MIDI** | ✅ **格式已冻结**（v1.1，见 §7.3.1）、**我方已按它实现**；✅ **离线解析层已验**（`evt2midi.py --selftest` 全过，判据含「文件头对**而且**内容对」）；✅ **上行链路/字节层已验**（PC 当 FPGA 灌 GPIO18 ⇒ ESP32 逐字节回到 PC，301 帧 / 4282 字节一致）；🔴 **未验的是【真 FPGA 产生的真事件】** —— ⚠️ FPGA 侧 2026-10-12 明确告知「14 B 事件帧的发送**尚未实现**」，他们现在发的是 **9 B 回传帧**（见 §7.5）。<br>🔴 **⛔ 不要写成「上行全通」** —— ⚠️ 那正是 `UART验收报告` 踩过的措辞坑（⭐ 把"字节层通"说成"链路通"） |

#### 🔴 2026-10-12 补：**USB 掉线**（⭐ 本轮遇到的新现象，⭐ 记下来）

⚠️ **现象**：`GetPortNames()` 里**没有** `COM29`，按 VID `303A` 查设备
⇒ `Status = Unknown`；`HKLM:\HARDWARE\DEVICEMAP\SERIALCOMM` 里也**没有**它
⇒ 🔴 **esptool 报 `FileNotFoundError(2, '系统找不到指定的文件。')`**（⛔ 不是"端口被占用"）。

⚠️ **判据（⭐ 用来区分"被占用"和"掉线"）**：

| 报错 | 含义 | 处理 |
|---|---|---|
| `could not open port ... 拒绝访问` / `PermissionError` | ⚠️ **端口在，被别人占着** | ⭐ 找占用进程 |
| `FileNotFoundError(2, '系统找不到指定的文件。')` | 🔴 **设备没了**（USB 链路断） | ⭐ **重插 USB**，⛔ 换端口名没用 |

🔴 **疑似诱因（⭐ 本轮实测）**：⭐ **批量 `Stop-Process` 杀 python 时误伤** ——
⚠️ 那些工具会**持有串口句柄**，强杀可能触发 USB 复位。
⇒ ⭐ **纪律：⛔ 不要用 `Get-Process python | Stop-Process -Force` 这种笼统杀法**
（⭐ 本轮同时误杀了 `python -m http.server 8777` —— 那是网页测试要用的）。
⭐ **正确做法**：⭐ **按 PID 精确杀**，且先确认那个 PID 不是别的用途。

⚠️ **`Get-PnpDevice` 的 `Status=Unknown` ⛔ 不等于设备不在** ——
⭐ 本机实测：CH340 也常年显示 `Unknown`，但**能正常打开**
⇒ ⭐ **判据要用 `GetPortNames()` / `SERIALCOMM` 注册表，⛔ 不要只看 `Status`**。

#### ⭐⭐ 2026-10-01 新增：阻塞已定位到【具体的 3 项改动】

⭐ **用户 2026-10-01 裁定 = 在 `PMOD0` 的 `G21`/`G22` 上新开【第二路 UART】**（⛔ **不复用** `J9` 那路）。
⭐ **完整对接单**（引脚 / 电平 / 接线 / 6 条判据 / 待裁定项）：
→ `files/20-代码/第二路UART对接单-给FPGA侧-20261001.md`

🔴 **阻塞的真正上游（⚠️ ⛔ 不是"引脚没分配"这么简单）**：

| ⭐ 事实 | ⭐ 权威依据（`FPGA2026\`，⛔ 不是本 worktree 旧快照） |
|---|---|
| FPGA **只有一对** UART 端口 | `rtl/top.v:416-417`（⭐ 之后即 `);`） |
| 它绑在 `J9` 的 `D14`/`D15`，**注释明写给 USB-TTL** | `constr/top.cst:364` / `:366` · `:352-353` |
| `PMOD0`（含 `G21`/`G22`）**仍未分配** | `constr/top.cst:137` |

⇒ ⭐ 所以要 FPGA 侧做 **3 项**：**新增端口** + **新增例化**（⭐ 照抄 `top.v:702` / `:945`，`.BAUD_DIV(100)` = 500 k）
+ **2 条 `IO_LOC`**。

⭐⭐ **最好的端到端判据（⭐ 人耳可判，⛔ 不需示波器）**：
⭐ **ESP32 发单字符 `'B'` ⇒ 板子上的【节拍器开/关】**
（⭐ `FPGA2026/rtl/top.v:453-459`：串口 `'B'` = `calib_cmd.CMD_METRONOME`）。

### 🥉 P2 —— **上行格式冻结**（⭐ 等 FPGA 侧回函）

⭐ 我方能做的**准备**：⭐ 把 `frame_format.py` 的 `FRAME_LEN_BY_TYPE` 扩到上行帧，
⭐ 并写好**双向**的解析 + 自检（⭐ 等对方一定稿就能立刻验）。

### ⭐ P3 —— **屏上剩余两项**（⭐ 2026-10-12 已分流，⛔ 不再混在一起）

| 项 | 归属 | 说明 |
|---|---|---|
| `LINK_LOST` 恢复 | ✅ **已完成** | ⭐ 用户裁定「重连 ⇒ 显示就绪」⇒ 已实现 + 已有判据 `L4_RECOVER`（见 **§7.2.1**） |
| `UNDERRUN` | ⛔ **已裁定不做** | ⚠️ 用户早先裁定「先不做」⇒ 见 **§7.1**，⛔ **别当成漏修的 bug**（🔴 本轮我自己就差点误判） |
| `t4`（缓冲水位） | ⛔ **已裁定不做** | ⚠️ 屏 320×240 位置不够 ⇒ 见 **§7.1** |

---

## 九、⭐⭐ 子代理分配建议（⭐ 怎么并行）

### ⭐ 判据：⭐ **任务 A 的产物 ⛔ 不是任务 B 的输入 ⇒ 才独立**

| ⭐ 可并行组 | ⭐ 子代理 | ⭐ 交付 | ⭐ 判据 | ⚠️ 文件边界（⭐ **必须互斥**） |
|---|---|---|---|---|
| ⭐ **组 1** | ⭐ A：**上位机 MIDI 通路** | ⭐ `evt2midi` 支持**上行帧** | ⭐ 合成上行字节 ⇒ 转出 MIDI ⇒ **能被播放器打开** | ⭐ `esp32/tools/evt2midi/**` |
| ⭐ | ⭐ B：**文档补全** | ⭐ 事实表 / 接口单更新 | ⭐ 每条都带**可核验判据** | ⭐ `files/20-代码/**`（⭐ 只碰**新**文件） |
| ⭐ | ⭐ C：**屏的剩余两项设计** | ⭐ `UNDERRUN` / `LINK_LOST` 恢复的**设计文档**（⛔ 不写码） | ⭐ 枚举**所有**状态迁移路径 | ⭐ `files/20-代码/**`（⭐ 与 B **不同文件**） |

### 🔴 分派铁律

| # | ⭐ 规则 |
|---|---|
| **1** | ⭐ **每个子代理负责的文件 / 目录必须互斥** —— ⚠️ 两个子代理写同一文件 = **互相覆写**（🔴 最难查） |
| **2** | 🔴 **子代理 ⛔ 不许做 git 写操作**（⭐ `commit`/`reset`/`checkout`/`merge`）—— ⭐ **只允许主会话做** |
| **3** | ⭐ **任务书必须自包含** —— ⭐ 子代理**看不到对话** ⇒ ⭐ 背景/路径/约束/交付格式全写清 |
| **4** | ⭐ **判断权 ⛔ 不外包** —— ⭐ 子代理的结论是**输入**，⭐ 最终结论由主会话负责 |
| **5** | ⭐ **⛔ 不许把有依赖的任务硬拆成并发** —— ⭐ 不确定独立不独立 ⇒ ⭐ **按不独立处理**（串行） |

### ⚠️ **⛔ 不能并行的**（⭐ 有依赖）

- 🔴 **改固件 + 编译 + 烧录 + 上板测** —— ⭐ 严格**串行**（⭐ 编译读源文件，⭐ 边改边编会**污染构建**）
- 🔴 **改 `frame_format.py` + 改 `evt2midi.py`** —— ⭐ 后者**依赖**前者的接口 ⇒ ⭐ 串行

---

## 十、⭐⭐ 交接 prompt（⭐ 直接复制给下一个会话）

```text
你是 ESP32 线工程师，接手「FPGA2026 纯硬件实时音频合成」的 ESP32 部分。

【先做这三件事，⛔ 不要跳过】
1. 读交接文档：C:\Users\hokuu\Desktop\FPGA\FPGA2026-esp32\files\20-代码\ESP32线交接文档-20261001.md
2. 读经验库索引：C:\Users\hokuu\Desktop\经验\README.md（⭐ 血泪索引按【症状】查）
3. 跑一遍自检确认基线：
   cd C:\Users\hokuu\Desktop\FPGA\FPGA2026-esp32\esp32\tools
   python selftest_all.py
   ⭐ 期望：41 个工具 / 856 项 / 0 RED
4. ⭐ 若要上机：照 `files\20-代码\待上机验证清单-20261014.md` 跑
   （含"板子接上该按什么顺序跑、每步判据、红了看哪张表"）

【硬边界 —— ⛔ 违反会毁掉队友的工作】
· 仓库/worktree：C:\Users\hokuu\Desktop\FPGA\FPGA2026-esp32（🔴🔴 **2026-10-01 修正**：⚠️ 原文写「⛔ 不是 FPGA2026，两个同时开着」⇒ 🔴 **把两者说成了两个独立仓库，实测不成立**。⭐ 真实关系 = **同一个 git 仓库的两个 `git worktree`，共用同一个 `.git`**（⭐ `git rev-parse --git-common-dir` = `…/FPGA2026/.git`；`git worktree list` = 22 个）。⚠️ **ref/tag 共享、HEAD/索引各自**；⚠️ **但 `rtl/` 内容不同（本 worktree 是旧快照）** ⇒ 核对 FPGA 侧去 FPGA2026。⭐ 依据 `esp32/README.md:81-89`）
· 分支：feat/s3-ble
· ⭐ 只能改 esp32/** 和 files/**；rtl/ constr/ tb/ sim/ bringup/ 是 FPGA 线的，⛔ 只读
· 🔴 WS2812 灯必须保持关闭（用户说"安全第一"，它有锁存，能扛过重启）
· ⭐ 改工程/写总结前先 git fetch；⚠️ 远端领先时 ⛔ 不要直接 reset --soft

【纪律】
· ⭐ 本地 commit 不限；🔴 push 必须先问用户
· ⭐ push 前必须把本周期所有提交压成 1 个（先 tag pre-squash/<日期> + git bundle 到仓库外）
  🔴 打完 tag 必须核对 `git tag --points-at HEAD` 【非空】—— ⚠️ 因 tag 是 22 个 worktree 共享的命名空间，
     ⭐ 名字很可能已被另一条线占用 ⇒ "存在就跳过"的守卫会【静默跳过】⇒ ⚠️ HEAD 其实没被钉住
· ⛔ 禁止 push --tags / push --all
· ⭐ 经验库满 10 条新条目才自动 push，不足只 commit
· ⛔ 经验库禁止 git add -A / git add .（公开仓库，历史误推过含订单号的备料.md）
· ⚠️ 经验库有另一条线在同时录入 ⇒ 编号取【当前最大值+1】，写完核对重号

【当前状态】
· ⭐ 串口屏 HMI 全链路通过：屏上 6 栏全部跟着实际状态变
· ⭐ 本轮修了 4 个死功能：屏上"播完"、"就绪"、"待机"、曲名 g0
· ⭐ 关键教训（经验库 C141）：追根因⛔不要停在"他忘了"，要问"他为什么没这么写"
  —— 实测：绕过公共封装的真因是【函数没有前向声明 ⇒ 调不到】
· ⭐ 19 个工具 / 317 项 / 0 RED；⚠️ **本地领先远端若干提交未推**（⭐ **以 `git status -sb` 的 `ahead N` 为准**，⛔ 不写死数字 —— 🔴🔴 **2026-10-01 修正**：⚠️ 原文写死「21 个」，⭐ 实测 `ahead 22`）

【最易踩的坑（都在交接文档 §二/§四）】
· ⚠️ 起播提前量 BLE_POOL_LEAD_TICKS = 20000 tick ≈ 10.4 秒
  ⇒ 放完时刻 = 10.4s + 谱面时长（⛔ 不能只按谱面时长等）
  ⇒ 一律从 ble_config.h 读，⛔ 不写死
· ⚠️ 屏的回包【不走 BLE】，只出现在 ESP32 的【串口日志】里
· ⚠️ 固件 RX 缓冲只有 32 B ⇒ 长回复【分多行日志】⇒ 要拼到 FF FF FF
· ⚠️ 串口号会漂 ⇒ 按 VID 找（ESP32=303A / 屏=FAED / CH340=1A86）
· ⚠️ build.ps1 的 -Action 是必填参数

【下一个目标（按优先级）】
P0 ⭐ push（等用户一句话；先压缩成一个提交）
P1 ⭐ 接 FPGA 端到端 —— 唯一的大块缺口
     · G21/G22 引脚分配（🔴 阻塞，等 FPGA 侧）
     · ESP32→FPGA 实音验证（🔴 阻塞）
     · FPGA 回传事件 → MIDI（⚠️ 可先离线用合成数据验证，不阻塞）
P2 ⭐ 上行帧格式冻结的准备（等 FPGA 侧回函，但我方可以先把解析+自检写好）
P3 ⚠️ 屏上 UNDERRUN / LINK_LOST 恢复（需用户先裁定语义）

【工作方式】
· ⚠️ 长任务（>3 分钟：编译/烧录/回归）一律 run_in_background，⛔ 不要前台等
· ⭐ ≥2 个【彼此独立】的任务 ⇒ 开子代理并行；⚠️ 但子代理⛔不许做 git 写操作，
  且每个子代理负责的文件必须互斥
· ⭐ 有疑问就问用户（给出选项），⛔ 不要私自揣测
· ⭐ 每轮必须留下可见正文（结论 + 数字 + 下一步），⛔ 不要把结论只写在思考里
· ⛔ 禁止吟唱（英文过程播报如 "Now..." / "Committing."）

【本轮已确认的判据风格（照这个来）】
· ⭐ 改 bug 要改【上游源头】，⛔ 不只改表象
· ⭐ 修完要把"不再犯"变成【机械检查】（⛔ 不是"记得以后别忘"）
· ⭐ 检查必须有【非空洞性】证明（合成一个必红的样本 ⇒ 必须报红）
· ⭐ "读回对" ≠ "人看到对" —— 值/显示/重绘是【三件事】（C139）
```

---

## 十一、⭐ 关联文档

| ⭐ 文档 | ⭐ 内容 |
|---|---|
| `files/20-代码/ESP32通路交接文档-20260922.md` | ⭐ **上一版**交接（⭐ 架构层面仍有效） |
| `files/20-代码/ESP32通路总体架构-20260922.md` | ⭐ 总体架构 |
| `files/20-代码/用户裁定结果-20260930.md` | ⭐ 模式 B / 起播归属等裁定 |
| `files/20-代码/矛盾裁定单-方案3与模式B-20260930.md` | ⭐ 为什么"起播归 ESP32" |
| `files/20-代码/反向通路对接单-给FPGA侧-20260930.md` | ⭐ 上行通路对接（⭐ 等回函） |
| `esp32/evidence/串口屏HMI验收报告-20261001.md` | ⭐ 屏的完整验收 + 判读表 |
| `esp32/evidence/状态机梳理-20261001.md` | ⭐ 8 个状态逐条枚举 + 3 个根因 |
| `esp32/README.md` | ⭐ 事实表（⭐ **§〇之二**，17 行）+ 读 `file:line` 的优先级说明 |
