hokuu1102/Gowin2026-PolySynth/files/20-代码/ESP32通路交接文档-20260922.md

# 📡 ESP32（经典版）通路 · 开发交接文档（2026-09-22 夜）

> 🔴🔴 **2026-10-01 更正（⭐ 第二轮文档审计）：⚠️ 本文是 2026-09-22 的【交接快照】，⛔ 不要照正文接手！**
>
> ⚠️ **本文下面第 11 行写的「ESP32 侧【零代码】」已完全作废** ——
> ⭐ **ESP32 侧现已落地并上机验收**（⭐ 205 帧验收 `total=200`/`tf=1`/`rst=4`/`unk=0`/`ovf=0`/`mismatch=0` 全过，
> `esp32/evidence/205帧BLE验收报告-20260930.md`）。
>
> ⭐ **现行事实一律以** `files/00-总览/交接文档-20260930.md` §〇之二 **与** `esp32/README.md` §〇之二 **为准**（⭐ **接手请从 `esp32/README.md` 进**）：
>
> | # | ⭐ 现行事实（2026-10-01） | 🔴 本文正文（已作废） |
> |---|---|---|
> | **1** | ⭐ **ESP32 侧【已有代码且已上机验收】**；⭐ 主推 `esp32/ble/`（ESP32-S3 + BLE） | 第 11 行「🔴 **ESP32 侧【零代码】**」；⭐ 全篇按**初代 ESP32 + SPP**写 |
> | **2** | ⭐ **波特率 = `500000`**（🔴 不是 1 Mbps、不是 115200） | 正文 §一 更正 5 / §二 / §五 多处写 **1 Mbps**、§「FPGA 侧现值 115200」 |
> | **3** | ⭐ **模式 B（水池）已是默认** | 正文按"先模式 A"写 |
> | **4** | ⭐ **`0xABF3` 七个命令**（`0x01`/`0x02`/`0x03`/`0x04`/`0x20`/`0x21`/`0x22`）· ⭐ **`0xABF4` 八组，且是【拉取快照】**<br>🔴🔴 **2026-10-01 修正（本行自身曾过期）**：⚠️ 原写「四个命令」⇒ ⭐ 实测 `case 0x01`/`0x02`/`0x03`/`0x04`/`0x20`/`0x21`/`0x22` @ `ble_main.c:659`/`673`/`691`/`696`/`712`/`724`/`753`；⚠️ 原写「六组 / 约 221 字节」⇒ ⭐ 实测格式串 **8 行**（`ble_main.c:419-435`），⛔ **字节数别写死**（工程里 210/221/261/264 四个数并存） | ⚠️ 正文无 CMD/STAT 设计 |
> | **5** | ⭐ **反向通路已打通**（2000 字节 round-trip 一致）+ ⭐ `up_ring` **160 KB PSRAM** 蓄水/放水 | ⚠️ 正文无上行设计 |
> | **6** | 🔴 **板载 WS2812 已关闭**（`WS2812_ENABLE=0`）· ⭐ **flash = 16 MB** | — |
> | **7** | ⭐ **本 worktree 的 `rtl/` 是旧快照**（1710 行 vs main 3970 行）⇒ ⚠️ 核对 FPGA 侧请去 `FPGA2026`（main） | ⚠️ 正文多处直接引 `rtl/...` 行号 |
>
> ⚠️ **保留正文以供追溯**（⛔ 不删历史 —— ⭐ "**为什么换板/换协议**"的推理链仍然有效）。

> 🔴🔴 **2026-09-22 夜重大更正** —— ⭐ **本文原有 8 处错误已修正**（见 §十一「更正记录」）。
> ⚠️ **其中第 1 条是致命的**：⭐ **原定「ESP32-S3」在架构上不可行** ——
> 🔴 **S3 芯片没有经典蓝牙 BR/EDR** ⇒ ⭐ **SPP 无法实现** ⇒ ⭐ **方案改为【初代 ESP32（经典版）】**。
> ⭐ **另新增两份文档**（⭐ **先读它们**）：
> · `ESP32通路总体架构-20260922.md` —— ⭐⭐ **ESP32 侧主文档**（架构、模式 A/B、实测矩阵）
> · `FPGA侧对接清单-ESP32通路-20260922.md` —— ⭐ **给 FPGA 侧 agent 的清单**（含溢出分析）
>
> **读者**：⭐ **接手 ESP32 通路开发的新 AI 会话**（⭐ 文末附**可直接复制的启动 Prompt**）
> **状态**：🔴 **ESP32 侧【零代码】；FPGA 侧由【另一个人】负责**
> **依据**：`ESP32通路总体架构-20260922.md`（⭐ 主）· `上位机与ESP32通路实施计划.md` · `蓝牙需求分析与实施规划.md` · `Console引脚查证-20260922.md`
>
> ## 🔴🔴 **最重要的边界：本会话【只做 ESP32】，⛔ 不动 FPGA**
>
> | | 谁做 | 范围 |
> |---|---|---|
> | 🔴 **FPGA 侧**（`rtl/`、`constr/`、`tools/`） | ⛔ **不是本会话** | ⚠️ **另有人负责** ⇒ ⭐ **只读，⛔ 不改** |
> | ⭐ **ESP32 侧**（固件、接线、联调） | ⭐ **本会话** | ⚠️ 在**独立目录**里建工程 |
>
> ⚠️ **为什么强调**：⚠️ FPGA 那边**正在跑全量变异测试**（⭐ 它会**就地改 `rtl/` 再还原**）
> ⇒ 🔴 **任何人这时改 `rtl/` 都会互相覆盖**。
> ⭐ 而且 ⭐ **FPGA 侧接口已经冻结**（见 §2.3）⇒ ⭐ **按契约对接即可，⛔ 不需要读 RTL**。

---

## 〇、⭐⭐ 30 秒结论

| # | 结论 |
|---|---|
| **1** | ⭐⭐ **你的活只有一件：写 ESP32（经典版）固件（蓝牙 SPP ↔ 串口）** |
| **2** | 🔴 **芯片 ≠ S3** —— ⚠️ **S3 无经典蓝牙** ⇒ ⭐ **用【初代 ESP32】**（`ESP32-WROOM-32E`） |
| **3** | ⭐⭐ **⛔ 不需要 FPGA 就能开发和自测** —— ⭐ **用"回环测试"**（§三 第 2 步）：<br>PC ──蓝牙 SPP──> ESP32 ──串口──> USB-TTL ──> PC，⭐ **验证字节流逐字节一致** |
| **4** | ✅ **接口已冻结**（§2.3）⇒ ⭐ **照着做即可，⛔ 不用读 RTL、⛔ 不用等 FPGA** |
| **5** | ✅ **波特率 = 1 Mbps**（⭐ 由 FPGA 侧改，⚠️ ⛔ 不是你的活）<br>🔴 **但 FPGA 侧现在实际还是 115200** ⇒ ⭐ **固件把波特率做成可配置** |
| **6** | ⭐⭐ **分两步做**：⭐ **先模式 A（纯透传）**，⭐ **跑通后再上模式 B（水池）** |
| **7** | ⚠️ **硬件**：需 **`ESP32-WROOM-32E` 开发板**（⚠️ 现有那块**非原厂**，计划买正品）+ USB-TTL |

> ⭐⭐ **一句话**：⭐ **把 ESP32 做成一根"无线的 USB 线"** ——
> ⭐ **PC 怎么发、发多快，ESP32 原样照搬**，⛔ **不看内容、⛔ 不改内容**。
> ⚠️ **但有一条前提**（⭐ 见 §2.4）：🔴 **写 UART 的字节数必须是 9 的整数倍**。

---

## 一、⭐⭐ 第一件事：按顺序读这些（⛔ 别凭印象写代码）

| 顺序 | 文件 | 为什么读 |
|---|---|---|
| **1** | ⭐⭐ `files/20-代码/ESP32通路总体架构-20260922.md` | ⭐⭐ **本通路的【主文档】** —— 架构、模式 A/B、实测矩阵、关键技术事实 |
| **2** | `files/20-代码/上位机与ESP32通路实施计划.md` | ⭐ **链路 9 个环节、协议、缺口** |
| **3** | `files/20-代码/蓝牙需求分析与实施规划.md` | ⭐ **需求与红线** —— ⚠️ 哪些能做、**哪些碰红线** |
| **4** | `files/00-总览/未完成工作总账.md` | ⭐⭐ **所有"还没做"的唯一入口**（`U-20` = ESP32） |
| **5** | `files/10-硬件/板卡替换评估/Console引脚查证-20260922.md` | ⭐ **引脚真值**（⚠️ 换板刚改过，旧文档有错） |
| **6** | `files/20-代码/play_seq接口冻结契约.md` | ⭐ 事件格式（**冻结契约，⛔ 别改**） |

> ⚠️ **若你同时对接 FPGA 侧**，⭐ 另读 `FPGA侧对接清单-ESP32通路-20260922.md`。

---

## 二、⭐⭐ 当前状态（✅ 已核实，⚠️ 不是估计）

### 2.1 ✅ 已经做完的（⭐ 别再重复造）

| 环节 | 文件 | 验证状态 |
|---|---|---|
| ⭐ **MIDI → 事件流** | `tools/mid2evt.py` | ✅ 含 `kind=2` 换速、`timbre[8:7]`、hex↔CSV 往返校验 |
| ⭐ **试听（离线）** | `tools/evt2wav.py` | ✅ 含 `--hex`、按 MIDI 速度表渲染 |
| ⭐ **字节接收** | `rtl/w3c/uart_rx.v` | ✅ 真 115200 端到端、10 种字节、背靠背、毛刺抑制 |
| ⭐⭐ **帧解析** | `rtl/w3c/evt_uart_rx.v` | ✅ **12 项判据全过** + 变异体 **M73~M76（4/4 CAUGHT）** |
| ⭐⭐ **PC 侧打包 + 限速** | `tools/evt2uart.py` | ✅ ⭐ **含离线自检**（纯 Python 复刻 RTL） |
| ⭐⭐ **PC 模型 ↔ 真 RTL 对拍** | `tools/selftest_evt2uart.py` | ✅ **306 事件 EXACT MATCH**（已接入 `selftest_all.py`） |
| ⭐ **曲谱播放器** | `rtl/w3c/play_seq.v` | ✅ **14 项判据全过** + **M69~M72（4/4）** |
| ⭐ **事件合流** | `rtl/w3c/evt_merge.v` | ✅ 8 项判据 + **M64~M68（4/4）** |

### 2.2 ⭐ 你要做的（⚠️ 只有 ESP32 侧）

| # | 事项 | 规模 | 依赖 |
|---|---|---|---|
| **①** | ⭐⭐ **固件【模式 A】纯透传**（⭐ **先做这个**） | ⭐ **小**（⭐ 几十行） | ⚠️ 要 `ESP32-WROOM-32E`（⭐ **不是 S3**） |
| **②** | ⭐ **接线 + 回环自测**（⛔ 不用 FPGA） | ⭐ **小** | ⚠️ USB-TTL **须支持目标波特率** |
| **③** | ⭐ **PC 侧联调**（⭐ 配对后就是 `COMx`） | ⭐ **小** | ✅ ⭐ **`evt2uart.py` 零改动**（⚠️ 这是 SPP 相对 BLE 的最大优势） |
| **④** | ⭐ **固件【模式 B】二级水池**（⭐ **A 跑通后再上**） | ⚠️ **中**（+~50 行） | ⚠️ 要读 `tick`/`kind`，⚠️ 有溢出风险 |
| **⑤** | ⚠️ **（可选，优先级低）录音回传** | ⭐ **中** | 🔴 **要 FPGA 侧先有 `uart_tx.v`** ⇒ ⛔ **不归你** |

> 🔴 **FPGA 侧的事（`top.v` 接 UART、改波特率、`uart_tx.v`）⛔ 【不是你的活】** ——
> ⚠️ **另有其人**，而且 ⚠️ **那边正在跑全量变异测试**（⭐ 它会**就地改 `rtl/` 再还原**）
> ⇒ 🔴 **你去改 `rtl/` 会和它互相覆盖**。⭐ **按 §2.3 的契约对接即可。**

### 2.3 ⭐⭐ 冻结接口（⭐ 照着做，⛔ 不用读 RTL）

| 项 | ⭐ 值 | 备注 |
|---|---|---|
| **波特率** | ⭐⭐ **1,000,000（1 Mbps）** | ✅ **已拍板**（⭐ FPGA 侧改，⚠️ ⛔ 不是你的活）<br>🔴 **但 FPGA 侧【现在实际还是 115200】** ⇒ ⭐ **固件把波特率做成可配置**（见 §十一 更正 6） |
| **数据格式** | ⭐ **8N1**（8 数据位、无校验、1 停止位） | ⭐ LSB first（标准 UART） |
| **流控** | ⛔ **无**（不用 RTS/CTS） | ⚠️ 见 §4.4 的反压说明 |
| **电平** | ⭐ **3.3 V**（⚠️ 初代 ESP32 也是 3.3 V ⇒ **可直连**） | ⛔ 别接 5 V |
| **帧格式** | ⭐ **9 字节**：`0xA5` + 8 字节大端事件 | ⭐ 见下 |
| **复位序列** | ⭐ **9 的整数倍个 `0xA5`** | ⚠️ 硬约束，见下 |

**帧格式（⭐ 与 `rtl/w3c/evt_uart_rx.v` 严格对应）**：
```
byte 0     : 0xA5          帧头（固定魔数）
byte 1..8  : 64 bit 事件   ★ 大端（与 events.hex 顺序一致）
```

> ⭐⭐ **模式 A 下你不需要理解事件的【内容】** —— ⭐ **透传就行，一个字节都别动**。
> ⚠️ **但模式 B（水池）需要读两个字段**：`tick`（`word[63:44]`）与 `kind`（`word[10:9]`）。
> ⭐ **见 `ESP32通路总体架构-20260922.md` §2.2**。

> ⚠️ **必须知道**下面两条**结构约束**（⚠️ 违反会**静默出错**）：

| # | 🔴 约束 | 为什么 |
|---|---|---|
| **1** | ⭐ **一帧的 9 字节要【连续发】出去** | ⚠️ FPGA 有"**空闲归位**"（静默 ≥16 个字节时间就复位）<br>⇒ ⚠️ 中间停顿太久会**截断帧** |
| **2** | ⭐ **复位序列长度必须是 9 的整数倍** | ⚠️ FPGA 把"9 个 `0xA5`"当**复位标记整帧抑制**<br>⇒ ⚠️ 发 `9N+3` 个会残留 3 字节，**之后所有帧错位** |

### 2.4 🔴🔴 **约束 1 的量化 + 一条必须补的纪律**（⚠️ 2026-09-22 新增）

#### ① ⭐ 约束 1 的**精确**含义（⭐ 已查 RTL 源码）

| 事实 | 出处 |
|---|---|
| 门限 = **16 个字节时间** | `evt_uart_rx.v:78`（`GAP_BYTES = 16`） |
| ⭐ **空闲归位【只在帧中途】触发**：`idle_expired && (idx_q != 4'd0)` | `evt_uart_rx.v:203` |

⇒ ⭐⭐ **关键结论（⚠️ 原文档没写清楚）**：

> ⭐ **帧与帧之间可以任意停顿**（谱子时间，几百 ms 都行）—— ⛔ **不会触发归位**。
> 🔴 **只有"一帧内部"的 9 个字节被打断，才会截帧。**

**换算**：

| 波特率 | 1 字节 | **门限（16 字节）** | 一帧本身（9 字节） |
|---|---|---|---|
| 115200 | 86.8 µs | 1.39 ms | 781 µs |
| ⭐ **1 Mbps** | **10 µs** | 🔴 **160 µs** | **90 µs** |

#### ② 🔴 原文档说"纯字节流透传天然满足" —— **这句是错的**

⚠️ **原因**：🔴 **RFCOMM 是【字节流】，⛔ 不保留 `write()` 的边界** ⇒
⚠️ **PC 的一次 `write(9字节)` 到 ESP32 可能变成两次回调**，中间隔一个任务调度周期
⇒ 🔴 **远超 160 µs ⇒ 必然截帧**（⚠️ 而 **1 Mbps 对此毫无帮助** —— 瓶颈是调度周期，⛔ 不是 UART 速度）。

⭐ **必须补的纪律**：

| # | 🔴 纪律 | 说明 |
|---|---|---|
| **A** | ⭐⭐ **写 UART 的字节数恒为 9 的整数倍**（余数留到下次） | ⭐ **维护一个 0–8 的余数计数器**，只有凑够 9N 才写<br>✅ **仍然不看内容、不改内容** ⇒ ⭐ **仍然算透传** |
| **B** | ⭐ **块的字节数也必须是 9 的整数倍** | ⚠️ 若用"攒够 1 KB 再发"，**1024 不是 9 的倍数** ⇒ 🔴 **边界落在帧中间，照样截帧**<br>⭐ 正确值：**1026 B = 114 帧** |
| **C** | 🔴 **一帧的 9 字节必须一次写入**（⛔ 不分 9 次、⛔ 中间不 `delay`） | ⭐ 理由同上 |

> ⚠️ **为什么这条最重要**：🔴 **帧被拆散后，FPGA 侧表现为"默默少几个音"**
> —— ⚠️ 而 `resync_cnt`/`hdr_err_cnt` **不一定涨** ⇒ ⭐ **属于最难查的一类故障**。

---

## 三、⭐⭐ 任务：分步走（⚠️ 顺序不能换）

### ⭐⭐ 第 1 步（模式 A）：**固件：蓝牙 SPP ↔ 串口 透传**

> ⭐⭐ **关键设计决定（✅ 已拍板）**：**ESP32 只当中转，⛔ 不解析 MIDI**。

| 方案 | 谁解析 | 评价 |
|---|---|---|
| **甲** | ESP32 解析 `.mid` | ⚠️ 固件复杂（要移植 `mid2evt` 到 C） |
| ⭐ **乙** | ⭐ **上位机解析 → ESP32 纯透传** | ⭐⭐ **已拍板选这个** |

⭐ **理由**：① 固件简单不容易出问题 ② ⭐ **解析逻辑只维护一份**（在 `mid2evt.py`）
③ ⭐ **合规上更无可指摘**（⭐ ESP32 连数据内容都不看，纯粹搬运）。

**固件要做的**（⭐ 就这些）：
```
蓝牙 SPP 收到字节  →  原样转发到 UART2（→ FPGA）
UART2 收到字节     →  原样转发到蓝牙
```

⚠️ **纪律**：
| # | 纪律 | 备注 |
|---|---|---|
| **1** | 🔴 **⛔ 不要做"按行/按包"解析** | ⭐ 事件流不是文本，⛔ 没有"行"的概念 |
| **2** | ⭐⭐ **写 UART 恒为 9N 字节**（⚠️ **见 §2.4 ②**） | 🔴 **这是模式 A 唯一的关键要求** |
| **3** | 🔴 **一帧的 9 字节一次写入**（⛔ 不分 9 次、⛔ 中间不 `delay`） | ⭐ 同上 |
| **4** | ⚠️ **不要缓存整曲**（模式 A ⛔ 不需要） | ⭐ 几百字节够做帧对齐即可 |

> 🔴 **⚠️ 本文档原纪律 ①「收到一个字节就转一个」已【作废】** ——
> ⚠️ 它是基于"SPP 保留 write 边界"的**错误假设**写的（⭐ 见 §十一 更正 3）。

### ⭐⭐ 第 2 步：**回环自测（⛔ 不用 FPGA，⭐ 现在就能做完）**

> ⭐⭐ **这是本会话【最有价值】的一步** ——
> ⭐ **它把"蓝牙链路"和"FPGA"解耦**，⚠️ 出问题一眼能定位是哪边。

**接线（⭐ 回环）**：
```
PC ──USB──> ESP32（蓝牙）      ← 发
PC ──USB-TTL──> ESP32 的 UART2  ← 收（⭐ 把 ESP32 串口接到 USB-TTL）
```

| # | 判据 | 怎么测 |
|---|---|---|
| **1** | ⭐ **字节流逐字节一致** | ⭐ PC 发 N 字节，USB-TTL 端收到**完全一样**的 N 字节 |
| **2** | ⭐ **大文件不丢** | ⭐ 发 **≥100 KB**（⭐ 一首曲谱的量级），⛔ 一个字节都不许丢 |
| **3** | ⭐ **含 `0xA5` 的数据不特殊处理** | ⚠️ 故意发一串 `0xA5` ⇒ ⭐ **原样透传**（⛔ 不许被吞、不许被改写） |
| **4** | 🔴🔴 **帧内空隙 < 门限**（⭐ **判据 4 已重写**） | ⭐ **PC 侧记录【每个字节的到达时间戳】**，滑动扫所有 9 字节窗口，检查窗口内**最大相邻间隔 < 门限/2**<br>⚠️ 1 Mbps ⇒ 门限 160 µs ⇒ ⭐ **卡 80 µs**；115200 ⇒ 1.39 ms ⇒ ⭐ **卡 700 µs** |
| **5** | ⭐ **反向也通** | USB-TTL 发 → 蓝牙端收到一样的内容 |
| **6** | ⭐ **两种波特率都跑** | ⭐ **1 Mbps 和 115200**（⚠️ FPGA 侧现值是后者） |
| **7** | ⭐ **长稳** | ⭐ 连续 ≥30 min，⛔ 无错 |

> 🔴 **判据 4 是本次重写的关键**：⚠️ **原判据「背靠背无 >16 字节时间的停顿」没给可测方法** ——
> ⚠️ 而**只比对内容根本测不出帧内空隙**（⭐ 内容全对、帧被拆散 ⇒ FPGA 侧**默默少几个音**，
> ⚠️ 而 `resync_cnt`/`hdr_err_cnt` **不一定涨** ⇒ 🔴 **属于最难查的一类故障**）。
> ⇒ ⭐ **必须用"到达时间戳"来测**（⭐ 见 `ESP32通路总体架构-20260922.md` §6.2）。

> ⭐ **第 3 条仍然重要**：⚠️ `0xA5` 是**合法的载荷字节** ——
> ⚠️ 若固件里**任何地方对它做了特殊处理**，FPGA 侧就会**静默错位**。

### ⭐ 第 3 步（模式 B）：**二级水池**（⚠️ 第 1/2 步跑通后再上）

⚠️ **模式 B 的取舍、代价、风险** ⭐ **见 `ESP32通路总体架构-20260922.md` §2.2 与 §五**。
⭐ **先做模式 A** —— 它最容易验证，而且**不需要懂事件格式**。

### ⭐ 第 4 步：**接上 FPGA，端到端**

⚠️ **这一步需要 FPGA 侧先做完"接 UART"**（⛔ 不是你的活）⇒ ⭐ **先做前三步，等通知**。

- ⭐ 把 ESP32 的 UART2 接到 FPGA 的 `PMOD0`（`G21`=TX / `G22`=RX，⚠️ **交叉接**：TX↔RX）
- ⭐ PC 侧用现成的 `evt2uart.py`（⭐ 指向**蓝牙的 COM 口** —— ⚠️ **SPP 配对后就是个 `COMx`**）
- ⚠️ **对拍**：蓝牙通的**结果**要和**有线**一致
- ⚠️ **对拍前先看**：`frame_cnt_o` / `resync_cnt_o` / `hdr_err_cnt_o`（⭐ 详见 FPGA 侧对接清单 §七）

---

## 四、⚠️ 优先级与红线（⭐ 读这段能省很多时间）

### 4.1 🔴 **蓝牙不是计分核心**（⚠️ 诚实结论）

| 项 | 结论 |
|---|---|
| **赛题要求** | ⭐ **可选**（原文"**可搭载**"），⛔ **不是必需** |
| 🔴 **优先级** | 🔴 **低** —— ⛔ **不进核心评分公式** |
| 🔴 **最大风险** | 🔴 **"锦上添花"吃掉本该做地基的时间** |
| ⭐ **正确姿势** | ⭐ **留接口（零成本）→ 做完地基 → 有线跑通 → 再加蓝牙** |
| ⭐ **同条里的优先级** | ⭐ **`led_data`（拓展要求 4 前半句）⚠️ 高于蓝牙（后半句）** |

> ⭐⭐ **一句话**：**蓝牙是"有了更好"，⛔ 不是"没有就丢分"。**
> ⚠️ 但 ⭐ **本会话的活【很便宜】**（⭐ 透传几十行 + 回环自测）
> ⇒ ⭐ **性价比高，可以趁现在做掉**。

### 4.2 🔴🔴 **一条硬红线：ESP32 ⛔ 绝不碰音频/视觉的【生成】**

| 环节 | 谁做 | 为什么 |
|---|---|---|
| 解析 MIDI | 上位机 / ESP32 | ⛔ 不是实时任务 |
| **传输事件流** | **ESP32 透传** | ⛔ 不涉及音频生成 |
| ⭐⭐ **合成音频** | ⭐ **必须 FPGA** | 🔴 **评分核心**（逐样本实时） |
| ⭐ **可视化生成** | ⭐ **必须 FPGA** | 🔴 主办方答复③：**"视觉效果不要用 MCU"** |

> 🔴 **唯一的边界**：⭐ **ESP32 侧不能碰"声音是怎么产生的"** ——
> ⭐ **它只是一根线**。

### 4.3 ✅ **回传 MIDI 不碰红线**（⚠️ 已论证过，⛔ 别再纠结）

⭐ **回传"事件流/MIDI"**（`note_on`/`note_off`/tick）**不算"整段录音触发"**：

| 理由 | 说明 |
|---|---|
| ⭐ **MIDI 里没有声音** | ⚠️ 不是 PCM、不是波形 ⇒ ⭐ **不是"录音"** |
| ⭐ **规则原文点名要求了这件事** | ⭐ 与"曲谱自动演奏"是**同一件事** |
| 🔴 **但三条边界不能越** | ⚠️ **⛔ 不要把回传的数据再上传给 FPGA 播放**（那才接近红线） |

> ⚠️ **为什么⛔ 不用 WAV 回传**：⭐ 合规上更危险 + ⚠️ **数据量大 280 倍**。
> 🔴 **而且回传要 FPGA 侧先有 `uart_tx.v`**（⚠️ 目前不存在）⇒ ⛔ **本轮不做**。

### 4.4 ⚠️ **反压/流控：✅ 已拍板"先不做反向通道"**

> 🔴🔴 **2026-09-30 夜【作废】** —— ⭐ **用户拍板：反向通道【要做】。**
>
> | 项 | ⚠️ 原文（2026-09-22） | ⭐ 现行（2026-09-30 夜） |
> |---|---|---|
> | **反向通道** | ⛔ 先不做 | ✅ **要做** |
> | **理由** | ⚠️ 当时"不做流控"的同意语 | ⭐ 现在**要 FPGA 回传音乐事件** ⇒ 通道**必需** |
>
> ⭐ **本条的正确读法**：⭐ **原文的"不做反向通道"当时指【不做流控/背压】**（⭐ 语境看标题），
> ⚠️ **而不是"不允许任何 FPGA→ESP32 的数据"**。🔴 **但两种理解在文档里混着写，必须澄清。**
>
> ⭐ **现行结论**：
> · ✅ **数据回传（FPGA → ESP32 → PC）【要做】** —— ⭐ 见 `反向通路对接单-给FPGA侧-20260930.md`
> · ⚠️ **流控/背压：仍待定** —— ⭐ 若要做，需**新增一条 ESP32 → FPGA 的"忙"信号**
>   ⇒ 🔴 **那才是真正意义上的第二条反向线**
> · ⭐ **ESP32 侧现状**：✅ **已实现透明缓冲**（`up_ring.c/.h`，160 KB PSRAM，"蓄水/放水"）
>   ⭐ 满了**拒绝新的 + 记账**（`u_drop`）⇒ ⚠️ **即使没有流控也不会静默丢**
>
> 📌 **裁定出处**：`矛盾裁定单-方案3与模式B-20260930.md` §〇之前

⚠️ **FPGA 不会告诉 ESP32 它的缓冲区水位**（⚠️ **流控**仍未做）。
⇒ ⭐ **靠 PC 侧限速**（`evt2uart.py` 已实现：按谱子时间 + 提前 8 拍灌）。

> 🔴 **2026-09-30 追加更正**：⚠️ 上句"靠 PC 侧限速"**已不适用** ——
> ⭐ 用户 Q5 裁定「**不需要**」PC 侧限速 ⇒ ⭐ **改由 ESP32 的水池自己按谱面时间放水**（模式 B）。

⭐ **对你的影响**：⚠️ **几乎没有** ——
- ⭐ **模式 A**：你只做**透传**，⛔ **不需要实现任何流控逻辑**
- ⚠️ **但模式 A 下"缓冲区要大"这条是【错的】**（⭐ 见 §十一 更正 4）：
  🔴 **PC 已消除积压**，⚠️ 你只需**几百字节**做帧对齐
- 🔴 **模式 B 才需要大缓冲**（⭐ 整曲 ~92.6 KB），⚠️ **且那时溢出风险在你身上**（⭐ 见总体架构 §四）
- ⚠️ 若上板发现**丢事件/饿死**，⭐ 那时再加反向通道（⭐ **不是现在**）

> 🔴 **顺便说清一件事**：⚠️ **`setRxBufferSize` 与"防溢出"无关** ——
> ⭐ 它是**接收侧**缓冲（PC→ESP32），⚠️ 而 FPGA 溢出发生在**发送侧**。
> ⇒ ⭐ **别把这两个缓冲搞混**（⭐ 这是本文档原第 3 条纪律的误用）。

---

## 五、✅ 已拍板（⛔ 不要重新讨论）

| # | 问题 | ✅ **结论** | 谁做 |
|---|---|---|---|
| **1** | ⭐⭐ **波特率** | ⭐⭐ **1,000,000（1 Mbps）** | ⚠️ **FPGA 侧改**（⛔ 不是你的活） |
| **2** | 🔴 **有线阶段走哪路** | 🔴 **本条已作废（2026-09-30 深夜）**：⭐ **板载 USB-C 的串口走不通**（`BL616` 跑 `TangCore` 私有协议，⛔ 不透传 `T`/`S`/`X`）<br>✅ **正解 = 外接 USB-TTL 到 `J9` 排针**：`TX→N26`（`D14`）· `RX→N25`（`D15`）· ⭐ **500000** 8N1 | ⚠️ 同上 |
| **3** | ⭐ **ESP32 走哪路** | ⭐ **`PMOD0`（`G21`=TX / `G22`=RX）** | ⚠️ 接线（⭐ 你的活） |
| **4** | ⭐ **ESP32 职责** | ⭐ **只透传，⛔ 不解析 MIDI**（⚠️ 模式 B 例外，但它不解析**音符**，只读 `tick`/`kind` 用于限速） | ⭐ **你的活** |
| **5** | ⭐⭐ **芯片** | ⭐ **初代 ESP32（经典版，`ESP32-WROOM-32E`）** —— 🔴 **⛔ 不是 S3**（S3 无经典蓝牙） | ⚠️ **采购** |
| **6** | ⭐ **蓝牙协议** | ✅ **SPP**（稳定优先，不省电）—— ⚠️ **只有初代 ESP32 支持** | ⭐ **你的活** |
| **7** | ⭐⭐ **转发模式** | ⭐ **先模式 A（纯透传）**，⭐ **跑通后再上模式 B（水池）** | ⭐ **你的活** |
| **8** | ⭐ **回传（录音）** | ⚠️ **本轮不做**（⚠️ 要 FPGA 侧先有 `uart_tx.v`） | ⛔ 不归你 |
| **9** | ⭐ **本会话范围** | 🔴 **只做 ESP32，⛔ 不动 FPGA**（`rtl/`/`constr/`/`tools/` 只读） | — |

### 5.1 ⭐ 1 Mbps 的依据（⭐ 供你理解，⛔ 不需要你改）

⭐ **50 MHz 下 1 Mbps 是【零误差 + 偶数分频】**：
```
BAUD_DIV = 50 MHz / 1 Mbps = 50     ← ⭐ 整数，0.000% 误差，偶数分频
```

| 波特率 | `BAUD_DIV` | 误差 | 评价 |
|---|---|---|---|
| 115200 | 434 | +0.006% | ⚠️ 可用，但非整数分频 |
| ⭐⭐ **1000000** | ⭐ **50** | ⭐⭐ **0.000%** | ⭐⭐ **完美** |
| 3000000 | 17 | 🔴 **-1.961%** | 🔴 **不可用** |

> ⚠️ **诚实说明**：⭐ **不是"115200 不够用"** —— **实时事件流很稀疏**（占用率仅 5.4%）。
> ⭐⭐ **真瓶颈是"整曲预灌"**：`09_Conjurer` 104 KB ⇒ **115200 要 9.26 s，1 Mbps 只要 1.07 s**。

### 5.2 ⚠️ 给 FPGA 侧的提醒（⭐ 你不用做，但要【知道】，⚠️ 因为他一改波特率你就得跟着改）

| 文件 | 现值 | 要改为 |
|---|---|---|
| `rtl/w3c/uart_rx.v` | `BAUD_DIV = 434` | **`50`** |
| `rtl/w3c/evt_uart_rx.v` | `BAUD = 115200` | **`1000000`** |
| `tools/evt2uart.py` | `--baud` 默认 115200 | **`1000000`** |

> ⚠️ **这就是为什么波特率必须【先定死再开工】** ——
> 🔴 **你的固件波特率和 FPGA 的 `BAUD_DIV` 必须一致**，⚠️ 一边改了另一边没改 = **完全收不到**。

---

## 六、⭐⭐ 验收判据（⚠️ 每条都必须能失败）

### 6.1 ⭐⭐ 你【能独立完成】的（⛔ 不用 FPGA）

| # | 判据 | 怎么测 |
|---|---|---|
| **1** | ⭐⭐ **蓝牙字节流逐字节一致** | PC 发 N 字节 → ESP32 → USB-TTL → PC，⭐ **完全一样** |
| **2** | ⭐⭐ **大文件不丢字节** | ⭐ 发 **≥100 KB**（一首曲谱量级）⇒ ⛔ **一个字节都不许丢** |
| **3** | ⭐⭐ **`0xA5` 被原样透传** | ⚠️ 发一串 `0xA5` ⇒ ⭐ **原样出来**，⛔ 不许被吞/改写 |
| **4** | ⭐ **背靠背无长间隙** | 连续多帧，⛔ 中途无 >16 字节时间的停顿 |
| **5** | ⭐ **反向也通** | USB-TTL 发 → 蓝牙端收到一样的内容 |
| **6** | ⭐ **1 Mbps 下稳定** | ⭐ 用 **1 Mbps**（⭐ 与 FPGA 一致）跑完上面全部 |

> ⭐⭐ **判据 3 是最容易漏的**：⚠️ `0xA5` 是**合法载荷字节** ——
> ⚠️ 若固件里**任何地方**对它做了特殊处理，FPGA 侧就会**静默错位**（⭐ 而且**看不出错**）。

### 6.2 ⚠️ 需要 FPGA 侧就位后才能测（⭐ 不是你的活）

| # | 判据 | 说明 |
|---|---|---|
| **1** | ⭐ **发一条真曲谱，喇叭响** | ⚠️ 要 FPGA 侧先接好 UART |
| **2** | ⭐ **事件数守恒** | FPGA `evt_uart_rx.frame_cnt_o` == PC 发的条数 |
| **3** | ⭐ **`resync_cnt_o == 0`** | ⚠️ 非 0 = **帧被拆散**（⭐ 上板第一眼先看这个） |
| **4** | ⭐ **`hdr_err_cnt_o == 0`** | ⚠️ 非 0 = **失步或波特率不对** |
| **5** | ⭐ **`play_seq.evt_underrun_o` 不亮** | ⚠️ 亮了 = PC 发慢了（喂不饱） |

---

## 七、⛔ 硬约束

### 7.1 ⭐ 你的（ESP32 侧）

| # | 约束 |
|---|---|
| **1** | 🔴 **模式 A：透传就是透传** —— ⛔ **不看内容、⛔ 不改内容、⛔ 不按包/按行解析** |
| **2** | ⭐⭐ **写 UART 恒为 9N 字节**（余数留到下次）—— ⚠️ **见 §2.4 ②** |
| **3** | ⭐ **波特率 = 1 Mbps**，⚠️ **必须和 FPGA 一致**（⚠️ 一边改另一边没改 = 完全收不到）<br>🔴 **但 FPGA 侧现值是 115200** ⇒ ⭐ **固件做成可配置** |
| **4** | ⚠️ **电平 3.3 V** —— ⚠️ 初代 ESP32 也是 3.3 V ⇒ **可直连**，⛔ 别接 5 V |
| **5** | ⭐ **接线要【交叉】**：ESP32 的 TX → FPGA 的 RX（`G22`）；ESP32 的 RX ← FPGA 的 TX（`G21`） |
| **6** | 🔴 **⛔ 不要动 `rtl/` `constr/` `tools/`** —— ⚠️ **另有其人负责**，⭐ 而且那边**正在跑**（⚠️ 它会就地改 `rtl/` 再还原） |
| **7** | ⭐ **ESP32 代码放独立目录**（⚠️ 别混进 `rtl/`） |
| **8** | ⚠️ **⚠️ 模式 B 才需要大缓冲**（⭐ 模式 A ⛔ 不需要 —— ⭐ 原第 3 条「`setRxBufferSize` 要加大」**已更正**） |

### 7.2 ⭐ 项目通用（⭐ 你也会碰到）

| # | 约束 |
|---|---|
| **1** | ⭐ **push 必须先问用户**（唯一例外：经验库满 10 条自动 push） |
| **2** | ⭐ **push 前压成 1 个 commit** + ⭐ **先备份**（`git tag` + `git bundle` 到仓库外） |
| **3** | ⚠️ **`.ps1` 必须纯 ASCII**（⚠️ PS 5.1 把无 BOM 的 UTF-8 按 GBK 解 ⇒ 中文注释可能**改变语法**） |
| **4** | ⚠️ **写文件⛔ 不用 `"w"` 直接开** —— 先写 `.tmp` 再 `os.replace`（⚠️ 否则报错时**文件变 0 字节**） |
| **5** | ⭐ **长任务（>3 分钟）挂后台**，⛔ 不要阻塞等待 |
| **6** | ⚠️ **有疑问就问，⛔ 别猜**（⭐ 需求/接口有歧义时先停下来确认） |

---

## 八、⭐ 常用命令

```powershell
# ⭐ 回环自测：把一段字节流从蓝牙发过去，从 USB-TTL 收回来比对
#     （⚠️ 具体脚本要你写；⭐ 也可以直接用 evt2uart.py 当发送端）
python tools\evt2uart.py build\score\regen\09_Conjurer\events.hex --dry-run --bpm 168
#      ↑ ⭐ --dry-run 先验证"打包对不对"（⛔ 不用任何硬件）

# ⭐ 串口调试（⚠️ 自己选一个：PuTTY / minicom / python pyserial）
python -c "import serial; s=serial.Serial('COM7',1000000,timeout=1); print(s.read(9).hex())"

# ⚠️ 文档自查（⭐ 若你改了这个文档）
python tools\check_doc_refs.py  /  python tools\check_names.py
```

> ⚠️ **注意**：⭐ **`tools/` 下的脚本属于 FPGA 侧**（⚠️ 别人维护）。
> ⭐ **你只能【用】，⛔ 不要改** —— ⚠️ 有需求先提。

---

## 九、⚠️ 交接前必做（⭐ ESP32 侧）

| # | 事项 |
|---|---|
| **1** | ⭐ **固件代码入库**（⭐ 放独立目录 `esp32/`，⚠️ 别混进 `rtl/`） |
| **2** | ⭐ **写一份"怎么烧、怎么接线、怎么自测"的 README**（⚠️ 别人要能复现） |
| **3** | ⭐ **回环自测的结果留证据**（⭐ 日志/截图，⚠️ 空口说"能通"不算） |
| **4** | ⚠️ **把"与 FPGA 对接的状态"写清楚**（⭐ 哪些测过、哪些没测） |
| **5** | ⭐ **更新 `未完成工作总账.md`** 的 `U-20` |
| **6** | ⭐ **确认买到的板子真是 `ESP32-WROOM-32E`**（⭐ 跑 `esptool.py chip_id`，应报 `ESP32-D0WD-V3`） |

---

## 附 A · ⭐⭐ 可直接复制的启动 Prompt

```text
你是本项目的嵌入式工程师，接手「FPGA2026 纯硬件实时音频合成」项目的
ESP32（经典版）蓝牙 SPP 通路开发。

【最重要的边界】🔴 本会话【只做 ESP32】，⛔ 不动 FPGA。
  · rtl/ constr/ tools/ 是【别人的】，⭐ 只读，⛔ 不要改
  · ⚠️ 原因：FPGA 那边正在改 rtl/（会就地改再还原）
            ⇒ 你去改 rtl/ 会和它互相覆盖
  · ⭐ 你按【冻结接口】对接即可，⛔ 不需要读 RTL

【第一件事】按顺序读这三个文件，读完再动手，⛔ 不要凭印象写代码：

1. files/20-代码/ESP32通路总体架构-20260922.md
     ⭐⭐ 本通路的【主文档】：架构、模式 A/B、实测矩阵、关键技术事实。
     ⭐ 先读它。

2. files/20-代码/ESP32通路交接文档-20260922.md
     ⭐ 本文件（含冻结接口、分步任务、验收判据、硬约束、§十一 更正记录）。

3. files/20-代码/蓝牙需求分析与实施规划.md
     ⭐ 需求与红线：⚠️ ESP32 ⛔ 绝不碰音频/视觉的【生成】；
        回传 MIDI 不碰红线（已论证，⛔ 别再纠结）。

【当前状态】（截至 2026-09-22 夜，已核实）
- 🔴 ESP32 侧【零代码】—— 你就是从零开始
- ✅ FPGA 侧已做完（帧解析 evt_uart_rx.v、uart_rx.v、play_seq.v、
     evt_merge.v、tools/evt2uart.py 含离线自检）
- 🔴 但 FPGA 侧【还没把 UART 接进 top.v】⇒ ⚠️ 端到端联调要等它
- ⚠️ FPGA 侧也【还没有"事件缓冲区"模块】（U-19 待拍板）⇒ ⚠️ 一起等
- ⚠️ FPGA 侧正在改 rtl/（我观察到 evt_uart_rx.v / evt_merge.v 都在变）⇒ ⛔ 别碰

【🔴🔴 芯片 —— 最容易搞错的一条】
- ⭐ 用【初代 ESP32（经典版）】，例如 ESP32-WROOM-32E
- 🔴 ⛔ 【不是 ESP32-S3】—— ⚠️ S3 芯片【没有经典蓝牙 BR/EDR】
      ⇒ SPP 在 S3 上【物理上不可实现】（只有 BLE）
- ⭐ 买到的板子先跑 `esptool.py chip_id`：⭐ 应报 `ESP32-D0WD-V3`
- ⚠️ 若报 ESP32-S3 / ESP32-S2 ⇒ 立刻停下告诉用户（芯片选错了）

【⭐ 冻结接口（照着做，⛔ 不用读 RTL）】
- 波特率：⭐ 1,000,000（1 Mbps）—— ⚠️ 必须和 FPGA 一致
      🔴 但 FPGA 侧【现在实际是 115200】⇒ ⭐ 固件做成【可配置】
- 格式：8N1，无流控，LSB first
- 电平：3.3 V（初代 ESP32 也是 3.3 V ⇒ 可直连，⛔ 别接 5V）
- 帧：9 字节 = 0xA5 + 8 字节大端事件
- 🔴 两条结构约束：
    ① 一帧的 9 字节要【连续发】（FPGA 有"空闲归位"：静默 ≥16 字节时间就复位）
         ⚠️ 已查 RTL 确认：🔴 归位【只在帧中途】触发
         ⇒ ⭐ 帧与帧之间可任意停顿；🔴 只有一帧【内部】被打断才截帧
         ⇒ 1 Mbps 下门限 = 160 µs；115200 下 = 1.39 ms
    ② 复位序列长度必须是 9 的整数倍（PC 发的 0xA5 串要原样透传）
- 🔴🔴 【必须补的一条纪律】：
      ⚠️ RFCOMM 是【字节流】，⛔ 不保留 write() 边界
      ⇒ 一帧可能被切成两次回调 ⇒ 中间隔一个调度周期 ⇒ 必然截帧
      ⇒ ⭐⭐ 【写 UART 的字节数恒为 9 的整数倍】（余数留到下次）
      ⇒ ⭐ 块大小也必须是 9N（⚠️ 1024 不是 9 的倍数，1026 = 114 帧才对）
      ⇒ ⭐ 一帧的 9 字节【一次写入】（⛔ 不分 9 次、⛔ 中间不 delay）
      ✅ 这仍然不看内容、不改内容 ⇒ ⭐ 仍然算透传

【你的任务：分步走（⚠️ 顺序不能换）】

第 1 步（模式 A）⭐⭐ 固件：蓝牙 SPP ↔ 串口【纯透传】
  ⭐ 已拍板：ESP32 只当中转，⛔ 不解析 MIDI（解析在上位机 mid2evt.py）
  固件就做：蓝牙 SPP 收到的字节 → 原样转 UART2；UART2 收到的 → 原样转蓝牙
  ⚠️ 纪律：
    ① ⛔ 不要做按行/按包解析
    ② ⭐⭐ 写 UART 恒为 9N 字节（余数留到下次）← 本条最关键
    ③ 🔴 一帧的 9 字节一次写入
    ④ ⚠️ 不要缓存整曲（模式 A ⛔ 不需要，几百字节够帧对齐）
  ⚠️ ⛔ 忽略旧文档的"收到一个字节就转一个"——那是错的前提

第 2 步 ⭐⭐ 回环自测（⛔ 不用 FPGA，⭐ 现在就能做完）
  ⭐ 这是最有价值的一步 —— 它把"蓝牙链路"和"FPGA"解耦
  接线：PC ──USB──> ESP32（蓝牙）发；USB-TTL ──> ESP32 的 UART2 收
  判据（⭐ 每条都必须能失败）：
    ① 字节流逐字节一致
    ② 发 ≥100KB 不丢一个字节
    ③ ⭐ 一串 0xA5 被【原样】透传（⛔ 不许被吞/改写）
    ④ 🔴🔴 帧内空隙 < 门限/2
         ⭐ 测法：PC 侧记录【每个字节的到达时间戳】，滑扫所有 9 字节窗口，
             检查窗口内【最大相邻间隔】
         ⚠️ 1 Mbps ⇒ 门限 160 µs ⇒ 卡 80 µs；115200 ⇒ 1.39 ms ⇒ 卡 700 µs
         ⚠️ 只比对内容【测不出】帧内空隙 ⇒ 必须用时间戳
    ⑤ 反向也通
    ⑥ ⭐ 1 Mbps 和 115200 【都要跑】（FPGA 侧现值是后者）
    ⑦ ⭐ 连续 ≥30 min 无错

第 3 步（模式 B）⭐⭐ 二级水池 —— ⚠️ 第 1/2 步跑通后再上
  ⚠️ 取舍/代价/风险见总体架构 §2.2 与 §五
  ⚠️ 模式 B 要读 tick（word[63:44]）与 kind（word[10:9]）用于自限速
  🔴 模式 B 有【溢出风险】（FPGA 无反向通道 ⇒ 你是盲发）

第 4 步 ⭐ 接上 FPGA，端到端
  ⚠️ 需要 FPGA 侧先做完"接 UART + 建缓冲区"（⛔ 不是你的活）⇒ 等通知
  接线：ESP32 的 UART2 → FPGA 的 PMOD0（G21=TX / G22=RX），⭐ 记得【交叉接】
  PC 侧用现成的 tools/evt2uart.py，⭐ 指向蓝牙的 COM 口
      （⭐ SPP 配对后在 PC 上就是个 COMx ⇒ ⭐ evt2uart.py 零改动）

【已拍板 —— ⛔ 不要重新讨论】
1. 芯片 = 初代 ESP32（经典版）—— 🔴 ⛔ 不是 S3（S3 无经典蓝牙）
2. 蓝牙协议 = SPP
3. 先模式 A（纯透传），跑通后再上模式 B（水池）
4. 波特率 = 1 Mbps（固件可配置；FPGA 侧现值 115200）
5. 有线阶段走 Console 板载 USB-C（FPGA 侧的事）
6. ESP32 走 PMOD0（G21=TX / G22=RX）← ⭐ 你的接线
7. 限速在 PC 侧（模式 A）；模式 B 才轮到 ESP32
8. 录音回传本轮不做（⚠️ 要 FPGA 侧先有 uart_tx.v）
9. 🔴 本会话只做 ESP32，⛔ 不动 FPGA

【硬约束】
- 🔴 模式 A：透传就是透传 —— ⛔ 不看内容、⛔ 不改内容
- ⭐⭐ 写 UART 恒为 9N 字节 ← 否则 FPGA 静默截帧
- ⚠️ 波特率必须和 FPGA 一致（一边改另一边没改 = 完全收不到）
- ⚠️ 电平 3.3V，⛔ 别接 5V
- 🔴 ⛔ 不要动 rtl/ constr/ tools/（⭐ 那边正在改 rtl/）
- ⭐ ESP32 代码放【独立目录】esp32/，⛔ 别混进 rtl/
- ⭐ push 必须先问用户；push 前压成 1 个 commit + 先备份
- ⚠️ .ps1 必须纯 ASCII（PS 5.1 按 GBK 解无 BOM 的 UTF-8）
- ⚠️ 写文件⛔ 不用 "w" 直接开：先写 .tmp 再 os.replace
- ⭐ 长任务（>3 分钟）挂后台，⛔ 不要阻塞
- ⚠️ 有疑问就问，⛔ 别猜

【常用命令】
  PC 侧打包自检（⛔ 不用硬件）：
    python tools\evt2uart.py build\score\regen\09_Conjurer\events.hex --dry-run --bpm 168
  串口调试（自己选工具：PuTTY / python pyserial）

现在：先写固件（第 1 步），再做回环自测（第 2 步）。
⭐ 这两步【完全不需要 FPGA】，⚠️ 不要等它。
```

---

## 附 B · ⭐ 一句话版

```text
接手 FPGA2026 的 ESP32（经典版）蓝牙 SPP 通路。先读
files/20-代码/ESP32通路总体架构-20260922.md（主文档），
再读本文件。

🔴 芯片：初代 ESP32（经典版，如 ESP32-WROOM-32E）
   —— ⛔ 不是 S3（S3 无经典蓝牙，SPP 不可实现）

🔴 只做 ESP32，⛔ 不动 FPGA（rtl/ constr/ tools/ 只读）——
   那边正在改 rtl/，你改会和它互相覆盖。

⭐ 你的活：把 ESP32 做成一根"无线的 USB 线"——收到的字节原样转发，
   ⛔ 不看内容、⛔ 不改内容、⛔ 不解析 MIDI。

⭐ 冻结接口：波特率 1 Mbps（固件可配置）/ 8N1 / 无流控 / 3.3V。
   帧 = 9 字节（0xA5 + 8 字节）。

🔴🔴 最关键的一条：写 UART 的字节数【恒为 9 的整数倍】——
   因为 RFCOMM 不保留 write() 边界，一帧可能被切成两次回调
   ⇒ 中间隔一个调度周期 ⇒ FPGA 空闲归位 ⇒ 静默截帧。

⭐ 分步：① 模式 A 纯透传 ② 回环自测（⛔ 不用 FPGA，现在就能做完）
       ③ 模式 B 水池（⚠️ A 跑通后再上）④ 接 FPGA（⚠️ 等 FPGA 侧）

⚠️ 自测最容易漏的：⭐ 帧内空隙必须用【到达时间戳】测
   （只比对内容测不出帧内空隙）
```

---

## 附 C · ⚠️ 本文件的边界（⭐ 诚实说明）

| # | 说明 |
|---|---|
| **1** | ✅ **芯片已定 = 初代 ESP32（经典版）** —— 🔴 **⛔ 不是 S3**（S3 无经典蓝牙 BR/EDR） |
| **2** | ✅ **波特率已定 = 1 Mbps**（⚠️ 但 FPGA 侧现值是 115200 ⇒ ⭐ 固件可配置） |
| **3** | ✅ **有线走板载 USB-C**；⭐ ESP32 走 `PMOD0`（`G21`/`G22`） |
| **4** | ⚠️ **ESP32 ↔ FPGA 的电平**：⭐ 官方 `.cst` 写 **`LVCMOS33`/3.3 V** ⇒ ⭐ **理论可直连**，⚠️ 但**上电前建议万用表实测** |
| **5** | ⚠️ **蓝牙吞吐未实测** —— 本文的"SPP 够用"是**按官方典型吞吐估算**的，⛔ 不是实测。⭐ **你的回环自测就是第一次实测** |
| **6** | 🔴 **事件缓冲区大小未定**（`U-19`）—— 🟡 建议 8 KB，⭐ 待拍板 ⇒ ⚠️ **FPGA 侧还没建这个模块** |
| **7** | ⚠️ **FPGA 侧还没把 UART 接进 `top.v`** ⇒ 🔴 **端到端联调要等通知**，⭐ 但 ⛔ **不阻塞前两步** |
| **8** | 🔴 **"开始播放"由谁发起 —— 协议里没定义**（⭐ 见 FPGA 侧对接清单 §五 问题 1） |
| **9** | ⚠️ **USB-TTL 芯片型号未确认** —— ⚠️ 部分 CP2102 上限就是 1 Mbps（无余量）⇒ ⭐ **回环自测前要看实物** |

---

## 附 D · 关联文档

| 想看什么 | 去哪 |
|---|---|
| ⭐⭐ **ESP32 侧主文档（总体架构）** | `files/20-代码/ESP32通路总体架构-20260922.md` |
| ⭐ **FPGA 侧对接清单（含溢出分析）** | `files/20-代码/FPGA侧对接清单-ESP32通路-20260922.md` |
| ⭐ 主计划（链路 + 协议） | `files/20-代码/上位机与ESP32通路实施计划.md` |
| ⭐ 需求与红线 | `files/20-代码/蓝牙需求分析与实施规划.md` |
| ⭐ 帧解析设计 | `files/20-代码/evt_uart_rx设计说明.md` |
| ⭐ 事件格式（冻结） | `files/20-代码/play_seq接口冻结契约.md` |
| ⭐ 引脚真值 | `files/10-硬件/板卡替换评估/Console引脚查证-20260922.md` |

---

## 十一、🔴 更正记录（⭐ 2026-09-22 夜）

> ⭐ **为什么要留这一节**：⚠️ **错误结论若不标出来，会被下一个会话当成事实继承**。
> ⭐ 本项目纪律：**推翻旧结论要当场改旧记录，保留"错误 → 修正"痕迹**（⛔ 不删历史）。

| # | 🔴 原来的写法 | ✅ 更正为 | 依据 |
|---|---|---|---|
| **1** | 「蓝牙走 **SPP**」（在 `ESP32-S3` 上） | 🔴 **S3 芯片没有经典蓝牙 BR/EDR** ⇒ ⭐ **改用【初代 ESP32】** | ESP-IDF 能力表：**只有初代 ESP32 一列 BR/EDR = Y**；ESP-FAQ 经典蓝牙页 AT 示例标题写死 `[ESP32 Only]`；`esp_spp` API 文档路径只有 `/esp32/` |
| **2** | 「ESP32-S3 的**具体型号**待确认」 | ⭐ **芯片选型本身错了**（⚠️ 不是"型号待确认"） | 同上 |
| **3** | 纪律①「⛔ 不要缓存整帧再发，**收到一个字节就转一个**」 | 🔴 **作废** —— ⚠️ **RFCOMM 不保留 `write()` 边界**，逐字节转发**不解决**帧被切分；<br>⭐ **改为「写 UART 恒为 9N 字节」** | 蓝牙 RFCOMM 是字节流（⭐ 无消息边界语义） |
| **4** | 「`setRxBufferSize` 要加大（预灌大文件不够）」 | ⚠️ **模式 A 下不需要** —— ⭐ 那是**接收侧**缓冲，⚠️ **与 FPGA 溢出（发送侧）无关** | `evt_uart_rx.v` 无 FIFO，⚠️ 溢出发生在发送侧 |
| **5** | 判据④「背靠背**无 >16 字节时间的停顿**」 | 🔴 **无法执行** —— ⚠️ **没给可测方法**，而只比对内容**测不出帧内空隙**<br>⭐ **改为「PC 侧记录每字节到达时间戳，滑扫 9 字节窗口查最大间隔」** | ⭐ 内容一致 ≠ 帧能拼起来 |
| **6** | 「波特率：**1,000,000**」（暗示已生效） | ⚠️ **FPGA 侧现在实际是 115200** ⇒ ⭐ **固件做成可配置** | `uart_rx.v:47` `BAUD_DIV = 434`；`evt_uart_rx.v:72` `BAUD = 115200` |
| **7** | 「纯字节流透传**天然满足**两条结构约束」 | 🔴 **在 RFCOMM 上不成立** | ⭐ 见更正 3 |
| **8** | 任务写「**三步走**」 | ⭐ **改为四步**（⚠️ 模式 B 是独立一步，不是"顺带做完"） | ⭐ 用户拍板：A 跑通再上 B |

### 11.1 ⭐ 新增的技术事实（⚠️ 原文档没有）

| # | 事实 | 出处 |
|---|---|---|
| **1** | ⭐ **空闲归位【只在帧中途】触发**：`idle_expired && (idx_q != 4'd0)`<br>⇒ ⭐ **帧与帧之间可任意停顿** | `evt_uart_rx.v:203` |
| **2** | ⭐ 门限 = **16 字节时间**（1 Mbps ⇒ **160 µs**；115200 ⇒ 1.39 ms） | `evt_uart_rx.v:78` |
| **3** | 🔴 **`evt_uart_rx` 自己不存数据** ⇒ 灌多快就往 FPGA 缓冲里灌多快 | `evt_uart_rx.v:89-90` |
| **4** | ⚠️ `uart_rx` **没有 `rx_busy_o`** | `uart_rx.v:53-54` |
| **5** | 🔴 **线速 11,111 事件/s ÷ 消耗 69.5 事件/s = 160 倍** ⇒ ⭐ **全速灌，8 KB 缓冲 92 ms 就满** | ⭐ 算术（⭐ 见 FPGA 侧对接清单 §2.2） |
| **6** | ⚠️ **`top.v` 里整条 UART 通路【还没接】**，⚠️ **事件缓冲模块也【不存在】** | `top.v` 全文 · `rtl/w3c/` 目录 |
| **7** | ⚠️ **1 Mbps 排空是 100 KB/s，⛔ 不是 125 KB/s**（8N1 = 10 bit/字节） | ⭐ 算术更正 |

### 11.2 ⭐ 仍然有效的部分（⛔ 没改）

| # | 内容 |
|---|---|
| **1** | ⭐ **帧格式**：9 字节 = `0xA5` + 8 字节大端事件 |
| **2** | ⭐ **复位序列长度必须是 9 的整数倍**（`RESET_FRAMES = 4` ⇒ 36 字节） |
| **3** | ⭐ **ESP32 ⛔ 绝不碰音频/视觉的【生成】**（红线，§4.2） |
| **4** | ⭐ **回传 MIDI 不碰红线**（§4.3，已论证） |
| **5** | ⭐ **引脚 `PMOD0`（`G21`=TX / `G22`=RX），交叉接** |
| **6** | ⭐ **`0xA5` 是合法载荷字节**，⛔ 不许被吞/改写 |
| **7** | ⭐ **蓝牙不是计分核心**（"可搭载"）⇒ ⚠️ 优先级低，⛔ 不进核心评分 |
