hokuu1102/Gowin2026-PolySynth/files/20-代码/ESP32通路总体架构-20260922.md

# 🏗️ ESP32 通路 · 总体架构（2026-09-22）

> 🔴🔴 **2026-10-01 更正（⭐ 第二轮文档审计）：⚠️ 本文是 2026-09-22 的【架构快照】，⛔ 不要照正文实现！**
>
> ⚠️ 正文里的「**波特率 1 Mbps**」「**初代 ESP32 / SPP**」「**先模式 A**」等**都已被后续裁定取代**。
> ⭐ **现行事实一律以** `files/00-总览/交接文档-20260930.md` §〇之二 **与** `esp32/README.md` §〇之二 **为准**：
>
> | # | ⭐ 现行事实（2026-10-01） | 🔴 本文正文（已作废） |
> |---|---|---|
> | **1** | ⭐ **波特率 = `500000`**（🔴 不是 1 Mbps、不是 115200）—— `BLE_BAUD` / `TEST_BAUD` / `BRIDGE_BAUD` 三处全 `500000`；⭐ FPGA 侧 2026-09-24 已降档（`FPGA2026/rtl/top.v:688` `.BAUD_DIV(100)`） | 正文 §一 第 5 行「⭐ **1 Mbps**（⚠️ 固件做成可配置）· ⚠️ FPGA 侧现值仍是 115200」 |
> | **2** | ⭐ **主推版本 = `esp32/ble/`（ESP32-S3 + BLE）**，⛔ 不是 SPP（⚠️ 带 PSRAM 的初代 `32E` **买不到**） | 正文 §一 第 1/2 行「初代 ESP32 · 经典蓝牙 SPP」 |
> | **3** | ⭐ **模式 B（二级水池）已是默认**，⛔ 不是"先做模式 A" | 正文 §一 第 3 行「先做模式 A（纯透传）」 |
> | **4** | ⭐ **`0xABF3` 有四个命令**（`0x01` 清池 · `0x02` 状态 · ⭐ `0x03` 起播 · ⭐ `0x04` 停止） | ⚠️ 正文**没有** CMD 口的设计 |
> | **5** | ⭐ **`0xABF4`(STAT) = 六组 / 约 221 字节**，🔴 **且是【拉取快照】**（⭐ 只有发 `CMD 0x02` 才刷新） | — |
> | **6** | ⭐ **上行通路已打通**（FPGA→ESP32→BLE→PC，⭐ 2000 字节 round-trip 逐字节一致）+ ⭐ `up_ring` **160 KB PSRAM** 蓄水/放水 | ⚠️ 正文**没有**上行设计 |
> | **7** | 🔴 **板载 WS2812 指示灯【已关闭】**（`WS2812_ENABLE=0` + `CLEAR_ON_BOOT=1`，⭐ 用户「安全第一」） | — |
> | **8** | ⭐ **flash = 16 MB**（`CONFIG_ESPTOOLPY_FLASHSIZE_16MB=y`） | — |
>
> ⚠️ **保留正文以供追溯**（⛔ 不删历史 —— ⭐ 它记录了"**为什么当时这么定**"，⭐ 那部分仍然有效）。

> **状态**：⭐ **方案已定案**（⭐ 2026-09-22 夜，用户拍板）
> 🔵 **2026-09-23 更新**：⭐ **FPGA 侧已答复对接清单的 4 个问题** ⇒ ⭐ **见 §九「FPGA 侧答复的落地影响」**
> **读者**：⭐ **ESP32 侧开发者** + ⭐ **FPGA 侧对接人**
> **定位**：⭐⭐ **本文件是 ESP32 通路的【主文档】** —— 交接文档只管"怎么接手"，本文件管"**架构为什么是这样**"
>
> **一句话**：⭐ **把 ESP32 做成一根"无线的 USB 线"** ——
> ⭐ **PC 怎么发、发多快，ESP32 原样照搬**，⛔ **不看内容、⛔ 不生成音频**。

---

## 一、⭐⭐ 已拍板（⛔ 不要重新讨论）

| # | 问题 | ✅ **结论** | 依据 |
|---|---|---|---|
| **1** | ⭐⭐ **用什么芯片** | ⭐ **ESP32（初代，经典版）** —— ⚠️ **⛔ 不是 S3** | 🔴 **S3 芯片无经典蓝牙 BR/EDR**，SPP 不可实现 |
| **2** | ⭐ **蓝牙协议** | ⭐ **经典蓝牙 SPP** | ⭐ 配对后**在 PC 上就是一个 `COMx`** |
| **3** | ⭐⭐ **转发模式（分两步）** | ⭐ **先做模式 A（纯透传）**，⭐ **跑通后再上模式 B（水池）** | ⭐ 用户拍板 |
| **4** | ⭐ **限速职责** | ⭐ **PC 侧**（`tools/evt2uart.py`，⭐ 已验证） | ⚠️ 模式 B 才轮到 ESP32 自限速 |
| **5** | ⭐ **波特率** | ⭐ **1 Mbps**（⚠️ 固件做成**可配置**） | ⚠️ FPGA 侧现值仍是 115200 |
| **6** | ⭐ **框架** | ⭐ **ESP-IDF** | ⭐ 用户拍板 |
| **7** | ⭐ **工程位置** | ⭐ `esp32/`（仓库根下） | ⛔ 不混进 `rtl/` |
| **8** | ⭐ **边界** | 🔴 **⛔ 不碰 `rtl/` `constr/` `tools/`** | ⚠️ 那边在跑变异测试（会就地改 `rtl/` 再还原） |

---

## 二、⭐⭐ 架构

### 2.1 模式 A · 纯透传（⭐ **先做这个**）

```
PC ──SPP(蓝牙)──> ESP32 ──UART2 1 Mbps──> FPGA ──> 合成 ──> 喇叭
     ↑
  evt2uart.py 限速（⭐ 已验证，⛔ 零改动）
```

| 项 | 值 |
|---|---|
| ESP32 角色 | ⭐ **透明的线** |
| 谁限速 | ⭐ **PC**（按谱子时间 + 提前量） |
| ESP32 要懂事件格式吗 | ✅ **完全不用** |
| 缓冲需求 | ⭐ **几百字节**（够做帧对齐即可） |
| 溢出风险 | ✅ **低**（PC 按提前量发，天然不超） |

**⭐ 唯一的固件要求（⚠️ 这条是关键）：**

> 🔴 **写 UART 的字节数恒为 9 的整数倍**（余数留到下次）。

⚠️ **为什么**：**RFCOMM 是【字节流】，⛔ 不保留 `write()` 的边界** ⇒
⚠️ 一帧的 9 字节**可能被切成两次回调**，中间隔一个调度周期（≫ 160 µs）⇒ 🔴 **FPGA 空闲归位 ⇒ 截帧**。

⭐ **9N 对齐仍然不看内容、不改内容** ⇒ ✅ **仍然算透传**。

### 2.2 模式 B · 二级水池（⭐ **A 跑通后再说**）

```
PC ──SPP(蓝牙)──> ESP32【水池 ~92.6 KB】──UART2 自限速──> FPGA
                   ↑
         ⚠️ ESP32 自己读 tick/kind 算发送时刻
```

| 项 | 值 |
|---|---|
| ESP32 角色 | ⭐ **小水库** |
| 谁限速 | 🔴 **ESP32 自己**（⚠️ PC 已退场） |
| ESP32 要懂事件格式吗 | 🔴 **必须读 `tick`（`word[63:44]`）与 `kind`（`word[10:9]`）** |
| 缓冲需求 | 🔴 **整曲 ~92.6 KB** |
| 溢出风险 | ⚠️ **有**（⚠️ 盲发，见 §四） |
| 换到什么 | ⭐ **断链/长卡顿也能继续播**（⭐ 见 §五） |

---

## 三、⭐⭐ 关键技术事实（⭐ 我逐个查过源码，⛔ 不是转述）

| # | 事实 | 出处 | 影响 |
|---|---|---|---|
| **1** | ⭐ **空闲归位【只在帧中途】触发**：`idle_expired && (idx_q != 4'd0)` | `evt_uart_rx.v:203` | ⭐ **帧与帧之间可任意停顿**（谱子时间），🔴 **只有帧【内部】被打断才截帧** |
| **2** | ⭐ 门限 = **16 字节时间** | `evt_uart_rx.v:78` | 1 Mbps ⇒ **160 µs**；115200 ⇒ **1.39 ms** |
| **3** | ⚠️ **`evt_uart_rx` 自己不存数据** | `evt_uart_rx.v:89-90` | ⚠️ **灌多快就往 8 KB 缓冲里灌多快** |
| **4** | ⚠️ `uart_rx` **没有 `rx_busy_o`** | `uart_rx.v:53-54` | ⚠️ 发送端无法感知"帧中途" |
| **5** | 🔴 **整曲 92.6 KB，FPGA 缓冲 8 KB**（差 11 倍） | `整曲缓冲大小定案.md` §2.4 | 🔴 **必须有节奏控制** |
| **6** | ⚠️ 系统**现在实际跑 115200** | `uart_rx.v:47`=434；`evt_uart_rx.v:72`=115200 | ⚠️ 固件必须可配置 |
| **7** | ⚠️ **`top.v` 里整条 UART 通路【还没接】** | `top.v` 全文 | 🔴 **端到端要等 FPGA 侧** |
| **8** | ⚠️ `evt2uart.py` 的限速依赖 `tick`/`kind` 两个字段 | `evt2uart.py:161,166` | ⭐ 模式 B 要 ESP32 自己实现同样的逻辑 |

### 3.1 ⚠️ 更正：1 Mbps 的真实排空速率

⚠️ **本文档早期版本写"125 KB/s"—— 这是错的**：

```
8N1 = 1 起始 + 8 数据 + 1 停止 = 10 bit/字节
1,000,000 ÷ 10 = 100,000 B/s = 100 KB/s     ← ⭐ 正确值
```

⭐ **受影响的口径**（⚠️ 结论不变，数字要改）：

| 链路 | 吞吐 | vs 100 KB/s |
|---|---|---|
| **SPP**（经典蓝牙实测） | 175–199 KB/s | ✅ **够** |
| BLE（⚠️ S3 才用） | 90–96 KB/s | 🔴 不够 |

---

## 四、🔴 溢出：为什么"防不住"，只能"看得见"

### 4.1 算一下（⭐ 这是"必须限速"的硬证据）

| 量 | 值 |
|---|---|
| 线速（1 Mbps, 8N1, 9 B/帧） | **11,111 事件/s** |
| 消耗（最密曲 `夜洋风景` @168 BPM） | **69.5 事件/s** |
| 缓冲（8 KB = 1024 事件） | — |

```
11,111 ÷ 69.5 = 160 倍        ← 生产比消费快 160 倍
1024 ÷ 11,111 = 92 毫秒       ← 全速灌，92 ms 就满
```

⇒ 🔴 **全速倒水 ⇒ 92 毫秒灌满 ⇒ 之后全部丢光。**

### 4.2 为什么是"开环"

⚠️ `上位机与ESP32通路实施计划.md` §4.4 已拍板 **"先不做反向通道"**

> 🔴🔴 **2026-09-30 夜更正**：⭐ **该拍板【已作废】** —— ⭐ 用户裁定 **反向通道要做**。
> ⚠️ **但本节的结论【仍部分成立】**：⭐ **"流控/背压"仍未做** ⇒
> ⭐ **FPGA 目前依然没渠道告诉发送端"我满了"** ⇒ ⭐ **限速仍靠发送端自觉**。
> 📌 差别：⭐ 现在**数据回传有了**（⭐ 但"忙"信号还没有）。
> 📌 出处：`矛盾裁定单-方案3与模式B-20260930.md` §〇之前

⇒ 🔴 **FPGA 没渠道告诉发送端"我满了"** ⇒ ⭐ **限速只能靠发送端自觉**。

### 4.3 ⭐⭐ 所以做法是：**让溢出必然可归因**

| 层 | 做法 |
|---|---|
| **L1 看得见** | 缓冲要有 `level_o`（水位）+ `high_water_o`（⭐ **sticky，在【丢失之前】就置位**） |
| **L2 算得出** | ⭐ **每一级的入/出都有计数，守恒等式闭合** |
| **L3 指得准** | ⭐ 丢事件时能**立刻判断是哪一级丢的** |

⭐ **守恒等式**（⚠️ 详见 `FPGA侧对接清单-ESP32通路-20260922.md` §三）：

```
PC 帧数 == frame_cnt_o == pushed == evt_cnt_o + 水位
evt_cnt_o == merged_cnt_o + drop_cnt_o + collision_cnt_o
merged_cnt_o == note_manager 受理数 + event_lost_cnt_o
```

> ⭐ **为什么用等式**：⚠️ "计数器没涨"只能证明**没记录到丢失**，⛔ **证明不了没丢**。

---

## 五、⭐ 模式 A vs 模式 B（⚠️ 用数据说话，不靠直觉）

| 维度 | **A · 直接传** | **B · 水池** |
|---|---|---|
| 防"蓝牙传错字节" | ⛔ **都不防** —— ⭐ **蓝牙链路层有 CRC + ARQ**，⚠️ 只会"卡/断"，⛔ **不会"悄悄改内容"** | ⛔ 同 |
| 卡 1–3 s | ✅ 无感 | ✅ 无感 |
| **卡 >11.4 s** | 🔴 **断音** | ⭐ **继续播** |
| **断连** | 🔴 断音 | ⭐ **继续播** |
| 限速在哪 | ⭐ **PC（现成、已验证）** | 🔴 **ESP32（要新写）** |
| ESP32 懂事件格式 | ✅ **不用** | 🔴 **要** |
| **溢出风险** | ✅ **低** | ⚠️ **有** |
| 复杂度 | ⭐ 低 | ⚠️ 中（约 +50 行） |

### 5.1 ⭐ "直接传"的抖动容忍度是**可调的**

⭐ 由**提前量**决定，⛔ 不用写固件：

| 提前量 | 容忍 @168 BPM | ⚠️ 上限 |
|---|---|---|
| 默认 8 拍 | **2.86 s** | — |
| ⭐ **32 拍** | ⭐ **11.4 s** | 🔴 **受 FPGA 那 8 KB 限制，再加无效** |

⇒ ⭐ **只有模式 B 能突破 11.4 s** —— 因为不这样的话瓶颈永远是 FPGA 的 8 KB。

### 5.2 ⭐ 结论

> ⭐ **要稳定性，靠"帧对齐 + 提前量"，⛔ 不是"囤多少"。**
> ⭐ **水池买到的是"断链容忍"，代价是"溢出风险 + 要懂事件格式"。**
> ⇒ ⭐ **所以 A 先跑通**（⭐ 它最容易验证），**再用同一套判据测 B**，用数据定死。

---

## 六、⭐⭐ 回环自测方案（⛔ 不需要 FPGA）

### 6.1 接线

```
PC ──USB──> ESP32（SPP）      ← 发送端
PC ──USB-TTL──> ESP32 的 UART2  ← 接收端（⭐ 带时间戳）
```

### 6.2 判据（⭐ 每条都必须能失败）

| # | 判据 | 怎么测 |
|---|---|---|
| **1** | ⭐ **字节流逐字节一致** | PC 发 N 字节 ⇒ 收到**完全一样**的 N 字节 |
| **2** | ⭐ **大文件不丢** | ⭐ 发 **≥100 KB**（⭐ 真实 `events.hex` 量级），⛔ 一个字节都不许丢 |
| **3** | ⭐ **`0xA5` 原样透传** | 故意发一串 `0xA5` ⇒ ⛔ 不许被吞/改写 |
| **4** | 🔴🔴 **帧内空隙 < 门限** | ⭐ **PC 侧记录【每个字节的到达时间戳】**，滑扫所有 9 字节窗口，检查窗口内**最大相邻间隔 < 门限/2**<br>⚠️ 1 Mbps ⇒ 门限 160 µs ⇒ **判据卡 80 µs**；115200 ⇒ 1.39 ms ⇒ **卡 700 µs** |
| **5** | ⭐ **反向也通** | USB-TTL 发 ⇒ SPP 端收到一样内容 |
| **6** | ⭐ **两种波特率都跑** | ⭐ 1 Mbps **和** 115200（⚠️ 有线阶段仍可能用后者） |
| **7** | ⭐ **长稳** | ⭐ 连续 ≥30 min，⛔ 无错 |
| **8** | 🔴 **【已起播】才看 underrun** | ⭐ **观察窗口从【已起播】算起**（⚠️ 见 §9.5）<br>⛔ 不能从"发送端开始发"算 —— 否则"灌完了人还没按键"会被**误判成 underrun** |

> 🔴 **判据 4 是最关键的一条** —— ⚠️ **只比对内容根本测不出帧内空隙**：
> ⭐ 内容全对、帧被拆散 ⇒ FPGA 侧**默默少几个音**，⚠️ 而 `resync_cnt`/`hdr_err_cnt` **不一定涨**。

> 🔴 **判据 8 是 2026-09-23 新增的** —— ⚠️ 因为起播改成了**上板手动按键**（⭐ 见 §9.2 / §9.5）：
> ⭐ **起播前 `play_seq` 不消费** ⇒ 缓冲水位不为 0、`evt_underrun_o` 的状态**都不代表故障**。

### 6.3 ⭐ 实测矩阵（一次跑完回答两个问题）

| | **@115200**（门限 1.39 ms） | **@1 Mbps**（门限 160 µs） |
|---|---|---|
| **模式 A** 透传 | ? | ? |
| **模式 B** 水池 | ? | ? |

---

## 七、⚠️ 未决项（⭐ 不阻塞模式 A）

| # | 项 | 状态 |
|---|---|---|
| **1** | ✅ **"开始播放"由谁发起** | ✅ **已答复** ⇒ ⭐ **方案③：上板手动按键**（⭐ 详见 §九） |
| **2** | ⚠️ **买哪块 32E** | ⚠️ 用户确认现有的是**开发板但非原厂** ⇒ ⭐ 计划买正品（⭐ 待执行） |
| **3** | ⚠️ **USB-UART 芯片型号** | ⚠️ 部分 CP2102 上限 1 Mbps（⚠️ 无余量）、CH340G 到 2 Mbps ⇒ ⭐ **回环前要看实物** |
| **4** | ✅ **缓冲深度定案（U-19）** | ✅ **已答复：采纳 8 KB / 1024 事件**（⭐ 带 `level_o` + `high_water_o` sticky）<br>🟡 ⚠️ 保留：**还要与 looper 3 层合账**，⚠️ 但**不阻塞开工** |
| **5** | ✅ **波特率是否参数化** | ✅ **已答复：做**（⭐ `uart_rx #(.BAUD_DIV(50))` 切档） |
| **6** | ✅ **空闲归位开着还是关着** | ✅ **已答复：开着**（`GAP_BYTES=16`）<br>⚠️ 我看到的 `1'b0` 是**变异体 M75 的中间态**（⭐ 见 §九.3） |

---

## 八、⭐ 工作物落地

```
esp32/                          ← ⛔ 独立目录，不混进 rtl/
├── bridge/      固件：初代 ESP32 / 经典蓝牙 SPP（⚠️ 已非主推）
│   ├── main/bridge_main.c      透传主逻辑 + 9N 对齐 + 帧头过滤
│   ├── main/bridge_config.h    ⭐ 唯一需要按现场改的地方
│   ├── main/pool.c / pool.h    模式 B：二级水池（⭐ tick 限流放水）
│   ├── main/hmi.c / hmi.h      ⭐ 串口屏驱动（TJC T1 2.0″）
│   ├── sdkconfig.defaults      预置 SPP ⇒ clone 即可编
│   └── build.ps1               构建/烧录/chipid（纯 ASCII）
├── ble/         ⭐⭐ 固件：ESP32-S3 / BLE（⭐ 主推，⭐ 默认模式 B）
│   ├── main/ble_main.c         GATT 服务 + 9N 对齐 + ⭐ 帧头过滤
│   ├── main/ble_config.h       ⭐ 唯一需要按现场改的地方
│   ├── main/gatt_svc.c / .h    GATT 属性表（UUID 照抄官方 ble_spp_server）
│   ├── main/pool.c / pool.h    模式 B：二级水池（⭐ 走 PSRAM）
│   ├── main/hmi.c / hmi.h      ⭐ 串口屏驱动（⭐ 与 SPP 版同一套）
│   └── sdkconfig.defaults      ⭐ 关键：BT_BLE_42_FEATURES_SUPPORTED / SPIRAM
├── tools/       回环自测 + 离线校验 + ⭐ PC 侧发送（⭐ 均支持无硬件自检）
│   ├── loopback_check.py       7 条判据，含【到达时间戳】帧内空隙判据
│   ├── pool_math_check.py      模式 B 的 tick<->us 换算复算
│   └── send_frames.py          ⭐ PC 侧"假 FPGA"：发总数帧 + 事件帧（--selftest）
├── 串口屏控件清单.md            ⭐ 7 个控件的 ID/坐标/字号（48 号字排版）
├── 串口屏上位机使用说明.md      ⭐ 建工程/字库/program.s/下载/自检
├── 串口屏指令表.md              ⭐ 可直接粘贴的调试指令（含 \xff 写法说明）
├── evidence/    实测矩阵日志（⭐ 空口说"能通"不算）
└── README.md    芯片识别三步法、两版区别、接线、关键纪律
```

> ⭐ **2026-09-23 更新**：补上 BLE 版固件目录（⭐ **主推**）与**串口屏三份文档**。
> ⚠️ 此前本节只列了 SPP 版固件目录 ⇒ **与实际不符**（⚠️ 会让读者以为只有 SPP 版）。
>
> 🔴🔴 **2026-10-01 修正：⚠️ 上面这棵树【仍不完整】—— 漏了实际存在的目录/文件。**
> ⭐ 实测 `esp32/` 下**多出**（⭐ 均已落地并验收）：
> · `esp32/ble/main/up_ring.c` / `up_ring.h` —— ⭐ 上行环形缓冲（**160 KB PSRAM**，"蓄水/放水"）
> · `esp32/ble/main/ws2812.c` / `ws2812.h` —— ⚠️ 板载 WS2812 驱动（⭐ **现已 `WS2812_ENABLE=0` 关闭**）
> · `esp32/uart_test/` —— ⭐ 独立诊断固件工程（`TEST_BAUD 500000`）
> · `tools/` 下**远不止 3 个**：⭐ 实测 **19 个工具**（⭐ `selftest_all.py` 枚举；含 `esp32/tools/evt2midi/` · `stat_read.py` · `regress_live.py` · `trigger_and_capture.py` …）
> · 顶层文档 ⭐ 还有 `esp32/README.md` · `上机指南.md` · `UART验证-不上FPGA.md` · `起播测试流程.md`（⭐ 树里未列）
> 📌 判据：⭐ `Get-ChildItem esp32 -Recurse` —— ⚠️ **树是快照，⛔ 别当清单用**。

⚠️ **已补**：`esp32/.gitignore` —— 现有 `/build/` **只挡仓库根目录**，
⚠️ 挡不住 `esp32/bridge/build/`、`sdkconfig` 等产物。
⚠️ **另排除** 厂商下载物目录（⭐ USART HMI 安装包 52.9 MB，⛔ 大二进制不入库）与 `*.log`。

---

## 九、⭐ FPGA 侧答复的落地影响（2026-09-23）

> ⭐ **答复原件**：`files/20-代码/FPGA侧答复-ESP32对接清单-20260923.md`
> ⭐ **我提的清单**：`files/20-代码/FPGA侧对接清单-ESP32通路-20260922.md`（§五 那 4 个问题）
> **结论**：⭐⭐ **4 个问题全部有答复；我的固件【一行都不用改】**

### 9.1 ⭐ 逐条答复

| # | 我问的 | ✅ 答复 | 对我固件的影响 |
|---|---|---|---|
| **1** | 🔴 "开始播放"由谁发起？ | ⭐ **方案③：上板手动按键**（`AB13`，`debounce` + 边沿 → `run_i`/`pos_reset_i`）<br>⛔ **不新增协议命令帧**<br>🔴🔴 **2026-09-28 更正**：⭐ `AB13` **已被【节拍器开关】暂时占用** ⇒ ⭐ **起播键改用 `Y12`**（⭐ 同 `BANK9`、⭐ 空闲） | ✅ **一行都不用改**（⭐ 只改"按哪个键"） |
| **2** | 缓冲深度定 8 KB 吗？ | ✅ **采纳 8 KB / 1024 事件** | ✅ 提前量取值有依据（⭐ 见 §9.4） |
| **3** | 空闲归位开着还是关着？ | 🔴 **开着**（⭐ 且确认我的 9N 对齐"**正好是正确对策，请保持**"） | ✅ **设计被确认** |
| **4** | 波特率最终值 + 参数化？ | ⭐ ~~**1 Mbps**（`BAUD_DIV 434→50`）+ ⭐ **参数化**~~<br>🔴🔴 **2026-10-01 修正：⚠️ 该"最终值"【已作废】** —— ⭐ 实测两侧最终定为 **`500000`**（`FPGA2026/rtl/top.v:702` `.BAUD_DIV(100)`；`esp32/ble/main/ble_config.h:84` `BLE_BAUD 500000`） | 🔴🔴 **2026-10-01 修正：⚠️ 原文写「✅ 与我固件默认值一致」⇒ 【已作废】** —— ⭐ 固件默认值**现在是 `500000`**（`ble_config.h:84`），⛔ 不是 1 Mbps |

### 9.2 ⭐⭐ 方案③ 的代价（⚠️ 用户已确认接受）

> ⭐ **用户 2026-09-23 拍板：接受方案③** —— 理由是**演示时人本来就在演奏位**。

| # | 代价 | 影响 |
|---|---|---|
| **1** | 🔴 **"灌完自动开演"不存在** —— 必须有人按一下 | ⚠️ 若将来要做"手机发谱、板子自己放"，⭐ **要重新谈**（回到方案②） |
| **2** | ⚠️ 做不到"播放中暂停/续播/跳到第 N 拍" | ⭐ 这些**目前不在本周计划里** |
| **3** | ⚠️ 起播时刻不由发送端控制 | ✅ **守恒等式验收不受影响**（计数与起播时机无关） |

> ⚠️ **为什么不是方案①（复位序列兼作 transport reset）**：⭐ **技术可行、成本仅一行**
> （`evt_uart_rx.v:187` 本就有 `all_a5_now` 检测），⚠️ 但**在"人在演奏位 + 有空闲按键"的前提下没有收益**，
> ⭐ 且本周主线是 W3a 采集链 ⇒ ⭐ **不该为曲谱线动冻结协议**。

### 9.3 ⚠️ 一条重要澄清：我看到 RTL"正在被改" = 变异测试的中间态

🔴 **FPGA 侧确认**：我在 `evt_uart_rx.v` 看到 `idle_expired` 被改成 `1'b0`，
⭐ **那是变异体 `M75`（"空闲归位关掉"）的中间态** —— `mutation_test.ps1` **就地改 RTL 再还原**。

⇒ ⭐ **教训（⚠️ 值得记）**：**在变异测试跑的时候，`rtl/` 任意文件都可能处于"被就地改"的中间态**
⇒ ⚠️ **读 RTL 得出的结论有可能是对着突变体得出的**。
⭐ 我这次的运气好：**读到的两个关键事实**（`GAP_BYTES=16`、`idx_q != 0` 才触发）**恰好没被改**，
⭐ 而且 FPGA 侧**独立确认了它们是设计意图**。

### 9.4 ⭐ 提前量（`BRIDGE_POOL_LEAD_TICKS`）的取值依据（⭐ 8 KB 已定案后复核）

| 曲子 | 换算 | 占 FPGA 缓冲（1024 事件） |
|---|---|---|
| `夜洋风景`（最密，99.3 事件/小节） | 5.21 小节 ≈ **517 事件** | **51%** ✅ |
| `09_Conjurer`（55.9 事件/小节） | 5.21 小节 ≈ **291 事件** | **28%** ✅ |

⇒ ⭐ **20000 tick 的取值仍成立** —— 留了近一半余量给突发和弦（单拍最多 24 条）。
⚠️ **但若 looper 后期扩容压缩了缓冲，这个数要重算**（⭐ 答复里保留了这一句）。

### 9.5 🔴🔴 两条验收判据的观察窗口要改（⭐ 因为起播改成手动）

> ⭐ **这是本轮答复里【对我影响最大】**的一条 —— ⚠️ 不改会看到**假失败**。

| 我的判据 | 受影响吗 | ⚠️ 怎么改 |
|---|---|---|
| **③ 守恒等式 ②③④⑤** | 🔴 **要改** | ⭐ **等式 ③④⑤ 只在【已起播】之后成立**<br>⚠️ 起播前 `play_seq` 不消费 ⇒ **水位不为 0 是正常的** |
| **⑧ `evt_underrun_o` 不亮** | 🔴 **要改** | ⭐ **观察窗口必须从【已起播】开始**<br>⛔ 不能从"发送端开始发"开始 —— ⚠️ 否则"灌完了人还没按键"会被误判成 underrun |
| ①②④⑤⑥⑦ | ✅ 不受影响 | ① 计数与起播时机无关；②④ 帧解析质量；⑤⑥⑦ 空闲归位相关 |

> ⭐ **FSide 同时确认了我的 §3.1 边界**：✅ **`pushed` 必须包含被抑制的全 `0xA5` 帧**
> （⚠️ 那 36 字节不产生事件但占线路时间）⇒ ⭐ **他们实现缓冲计数时会保证口径一致**。

### 9.6 ⛔ FPGA 侧本轮【不做】的（⭐ 明确边界，⛔ 不要等错东西）

| # | 不做 | 说明 |
|---|---|---|
| **1** | ⛔ 不新增协议命令帧 | ⚠️ **2026-09-30 夜【作废】** —— ⭐ 用户裁定走**模式 B**（ESP32 起播）⇒ ⭐ **需新增起播命令**<br>🔴🔴 **2026-10-01 修正：⚠️ 原文写「（⚠️ 待实现）」⇒ 【已作废】—— ⭐ 已落地并实测**：`case 0x03` 起播 @ `esp32/ble/main/ble_main.c:691` · `case 0x04` 停止 @ `:696`（⭐ 实测 `sent=200/200 rate=1919`，见 `esp32/evidence/放水时序验收报告-20260930.md`） |
| **2** | ⛔ 不做 `reset_seq_o` | ⚠️ 需要时一行就能加 |
| **3** | ⛔ 不做反向通道 | 🔴🔴 **2026-09-30 夜【作废】** —— ⭐ 用户裁定 **反向通道要做**（⭐ FPGA 回传音乐事件）<br>⚠️ **但"流控/背压"仍待定**（⭐ 那需要新增 ESP32 → FPGA 的"忙"信号）<br>📌 出处：`矛盾裁定单-方案3与模式B-20260930.md` §〇之前 |
| **4** | ⛔ 不写 ESP32 固件、⛔ 不动 `esp32/` | ⭐ 双方只读对方目录 |

> ⭐⭐ **2026-09-30 夜总更正**：⚠️ 本表第 **1**、**3** 两条**均已作废**。
> ⭐ 原因：⭐ 用户在 `待用户裁定问题清单-20260930.md` 里裁定
> **Q1 = 走模式 B（ESP32 起播）**、**Q3 = 反向通道要做**。
> 🔴 **请以 `矛盾裁定单-方案3与模式B-20260930.md` §〇之前 为准。**

### 9.7 🔵 一条连带更正（⭐ 影响手机端要做什么）

⚠️ FPGA 侧**更正了自己上一版的错误判断**：**串口屏不是加分项，而是已拍板的【主控制面】**。

| 项 | 结论 |
|---|---|
| **键位自定义** | ⭐ **放串口屏**（⭐ 脱机也能改，⛔ **不依赖手机**） |
| **串口屏与 ESP32 的关系** | ⭐ **两条独立 UART**（`J2` 屏 vs `PMOD0` ESP32）⇒ ⛔ **互不干扰，⛔ 不占蓝牙带宽** |
| ⇒ ⭐ **对 ESP32 通路的含义** | ⭐ **手机端只需做"曲谱下发"这一件事**（⚠️ 键位/模式/可视化都不归手机） |

### 9.8 ⚠️ 他们的落地排期（⭐ 明确说"不要催"）

> ⭐ 顺序：① 变异测试跑完收尾 ② **`PA_EN` 极性**（🔴 **不修板子仍然没声音**）
> ③ 波特率 + 起播键 ④ **W3a 采集链**（⭐ 本周硬指标：**手弹出声**）⑤ UART 通路接进 `top.v` + 缓冲

🔴 **关键**：**变异测试跑完前，他们⛔ 不能改 `rtl/` 任何现有文件**
⇒ ⭐ **"端到端联调"仍在排队**，⚠️ **但我的模式 A/B 固件都已就绪，⛔ 不阻塞**。

---

## 附 · 关联文档

| 想看什么 | 去哪 |
|---|---|
| ⭐ ESP32 侧交接（怎么接手） | `ESP32通路交接文档-20260922.md` |
| ⭐ **FPGA 侧对接清单（含溢出分析）** | `FPGA侧对接清单-ESP32通路-20260922.md` |
| ⭐⭐ **FPGA 侧的答复（2026-09-23）** | `FPGA侧答复-ESP32对接清单-20260923.md` |
| 帧解析设计 | `evt_uart_rx设计说明.md` |
| ⭐ 事件格式（冻结） | `play_seq接口冻结契约.md` |
| 缓冲定案（U-19） | `整曲缓冲大小定案.md` |
| 上位机通路计划 | `上位机与ESP32通路实施计划.md` |
| 蓝牙需求与红线 | `蓝牙需求分析与实施规划.md` |
