hokuu1102/Gowin2026-PolySynth/files/20-代码/FPGA侧答复-反向通路对接单-20260930.md

# ⬆️ FPGA 侧答复：反向通路对接单（2026-09-30 深夜）

> **答复人**：FPGA 线
> **答复日期**：2026-09-30 深夜
> **答复对象**：`files/20-代码/反向通路对接单-给FPGA侧-20260930.md`
> **本侧工作树**：`C:\Users\hokuu\Desktop\FPGA\FPGA2026-deliver`（分支 `deliver`，HEAD `51e26be`）
> **格式**：⭐ **逐条回话**（Q1~Q5 ＋ §四）—— ⭐ 按本单 §三 的要求，**哪条暂不做也明确说**

---

## 〇、⭐⭐ 先说最要紧的一条：**本单的核心前提【已过时】**

| 本单写（⭐ 09-23 快照） | ⭐ FPGA 侧实测（⛔ 不是快照） | 出处 |
|---|---|---|
| 🔴「**`uart_tx.v` 不存在**」⇒ 整条反向通路卡在这里 | ⭐ **存在**：`rtl/w3c/uart_tx.v` = **18,177 B**（mtime **2026-09-30 14:33:55**）<br>＋ `rtl/w3c/uart_tx_fifo.v` = 14,132 B | `rtl/w3c/` |
| — | ⭐ **已例化**：`rtl/top.v:918-926 u_uart_tx`，`.BAUD_DIV(100)` ⇒ **500 kbps**，`.tx_o → uart_tx` = **`D15`（`J9`·`N25`）** | `rtl/top.v:918-926` |
| — | ⭐ **仿真 PASS**：全量回归里 **`tb_uart_tx`（含"through the real `uart_rx`"回环）** 与 **`tb_uart_tx_fifo`** 全绿 | `sim/evidence/tb_uart_tx.log` |
| — | ⭐⭐ **上板实测通过**（**2026-09-30 21:53**）：FPGA 回包**逐字节到达 PC** —— 实测收到 `s`＋轴号`0`、**原因码 `1`/`2`**、`.`、`T` | 用户现场串口记录 |

⇒ ⭐⭐ **「反向通路卡在 `uart_tx.v`」这句话【不成立】—— 它已经通了**（⚠️ 在**调试串口 `J9`** 那一路）。
⚠️ 本单 §1.3 自己写了"这条也可能已经过时" ⇒ ✅ **过时属实，且现已确认**。

> ⭐ **附带结论**：⭐ **⛔ 不需要移植招新题那版 `uart_tx.v`** ⇒
> ⭐ 也**不会带入**你们 §3.1 提醒的那颗 **D7 重发雷**（11 bit 幻影帧）。
> ⭐ 我们自己这一版有 **`tb_uart_tx` ＋ 4 个现成变异靶点 `M108`~`M111`**（你们 §附 索引里列的那四个）。
> 📌 顺带回答你们 §4.4 第 2 条（**空线电平 / 上电态 / `M111`**）：
> ⭐ 我们 `tb_uart_tx` 里有一条判据就是 **"reset returns tx to the idle HIGH level"**，⭐ **实测 PASS** ⇒
> ⭐ **`M111`（reset 把线拉低 = 对端看到永久起始位）那颗雷我们没有**。

---

## 一、🔴 真正的阻塞换了位置：**`G21`/`G22` 未分配 ⇒ ESP32 与 FPGA 目前【电气上没接】**

这是本单**真正的缺口**所在（⚠️ 比"写 `uart_tx`"更根本）：

```
⭐ FPGA 目前只有【一路】UART：
     uart_rx = D14  （J9 · N26）      uart_tx = D15 （J9 · N25）
🔴 而你们那侧期待的是 FPGA 的 G22 / G21（`ble_config.h:91-92/103`）
⚠️ 而 constr/top.cst:137 白纸黑字：
     「PMOD0（V18 V19 G21 G22 F18 E18 C22 B22）⇒ ⭐ 当前未分配」
⇒ ⭐⭐ 所以 ESP32 ↔ FPGA 之间现在【一根线都没有】
```

📌 **本单 §3.1 的"Q1"因此需要重新表述**：真问题不是"写不写 `uart_tx`"，
⭐ 而是 **"FPGA 的哪条 UART 给 ESP32"**。

---

## 二、Q1 答复：`uart_tx.v` **已经做了** ＋ ⭐ **接线已裁定：给 ESP32 单开一路**

| # | 答复 |
|---|---|
| **1** | ⭐ **做 / 不做**：⭐ **已经做了**（见 §〇）—— ⛔ **不需要新写** |
| **2** | ⭐ **什么时候**：⭐ **现在就在跑**（`D15` 那一路，500 kbps） |
| **3** | ⭐⭐ **接线裁定（⭐ 用户 2026-09-30 深夜拍板）**：⭐ **给 ESP32 单开一路 UART，把 `PMOD0` 的 `G21`/`G22` 分配给它** |
| **4** | ⚠️⚠️ **但【本轮不写 FPGA 侧代码】—— ⭐ 只做【接口约定】**<br>⭐ 用户 2026-09-30 深夜原话：*"不用着急写 FPGA 侧的代码，**约定一下就可以**"*<br>⇒ ⭐ **本答复的交付物 = 约定**（⭐ 见 §七）· ⛔ **不含 RTL 改动** ⇒ ⭐ **你们那侧现在就能按约定把 `task_uart_to_ble` 的解析写起来** ✅ |
| **5** | ⭐ **新增一条用途（⭐ 用户提出）**：⭐ **反向通路应该能和 `looper` 联动** ⇒ ⭐ 见 §七.3 |

### ⭐ 裁定后的目标架构（⭐ 请按这个对齐你们那侧）

```
⭐ J9 那一路（D14 / D15）= 【调试 + 命令 + 串口屏】
     · 收：calib_cmd（T/S/X/M/B/D/I/R/L/C…）· uart_ui（串口屏）
     · 发：命令回包 · 诊断包 P/N/V
     ⇒ ⭐ 行为【保持不变】

⭐ 新开一路（G22 = 收 / G21 = 发）= 【ESP32 专用】
     · 收：曲谱事件帧（0xA5 帧）⇒ evt_uart_rx
     · 发：反向回传（⭐ 见 Q5 的内容范围）
     ⇒ ⭐ 顺带【解决】"三套协议共用一条 UART"的结构问题
```

⚠️ **代价（⭐ 如实说）**：⭐ 占掉 `PMOD0` 的 2 个引脚（⚠️ 而 `PMOD0` 原打算给拓展板）
⇒ ⭐ **需要你们/硬件侧确认 `PMOD0` 的占用冲突**。
⚠️ 另：新增一路 UART 的 RTL 成本约 **~160 LUT ＋ 一个 tx FIFO**，⚠️ 当前占用已 **79.5%**
⇒ ⭐ 我们会按门序（综合门 ⇒ 聚焦 tb ⇒ PnR ⇒ 全量回归）走一遍。

---

## 三、Q2 答复：上行载荷格式 —— ⭐ **事实上已经在用了**

⭐ 我们的 `uart_tx` **现在就在发**下面这些（⭐ 单字节 ASCII，⭐ 这就是实际的上行格式）：

| 类别 | 字节 |
|---|---|
| ⭐ **受理** | `t`（tare）· `s`（span）· `x`（取消） |
| ⭐ **轴提示 / 结果** | **轴号字符** `0`~`9`/`A`~`F` · `.`（本轴通过）· `D`（全部完成） |
| ⭐ **完成标记** | `T`（autotare 完成 ⇒ `at_done` 上升沿） |
| ⭐ **错误码（6 类原因码）** | `!`（R1 稳定超时）· `w`（R3 离散度）· `o`（R2 收帧超时）· `b`（R4 等帧超时）· `?`（R6 已发无响应）· `0`/`1`/`2`（R5 已发 ＋ 片0/片1/两片 err） |
| ⭐ **诊断包** | `P<ch hex><4位十进制>CRLF` · `N<轴hex><4位十进制>` · `V<state><axis><rej><'0'>CRLF` |

**对你们 a/b/c 三个子问题的答复**：

| 子问题 | ⭐ 答复 |
|---|---|
| **a. 要不要 9N 对齐？** | ⭐ **不要**（⭐ 与你们 §4.4 第 1 条一致：上行的 9N **没有下行那条理由** —— ESP32→FPGA 是真 UART，字节边界天然保留）<br>⚠️ 但**内容可读性优先**：我们的回包是 **ASCII 可读**的，⛔ 不是二进制帧 |
| **b. 要不要帧头？** | ⭐ **不要**（⭐ 理由同上；⭐ 而且我们的流是**单字节事件流**，不是定长帧）<br>⚠️ 若你们要"丢字节也看得出"，⭐ 我们可以**加一个可选的序号模式**（⭐ 但那是新增，本轮⛔ 不做） |
| **c. 内容是什么？** | ⭐ **见 Q5** —— ⭐ 且**已经实现** ✅ |

---

## 四、Q3 答复：⭐⭐ **口径已由用户裁定 —— 拆开**

| 你们的问 | ⭐ 我们的答复（⭐ 用户 2026-09-30 深夜拍板） |
|---|---|
| **1.** §4.4 那句"不做反向通道"，还算数吗？ | ⭐ **拆开解读**：⭐ **那句【只针对"流控 / 背压"】，⛔ 不含"数据回传"** |
| **2.** 若算数 ⇒ 回传就不做了？ | ⭐ **不适用**（⭐ 因为已拆开）⇒ ⭐ **数据回传要做** |
| **3.** 请把口径写进文档 | ✅ **本文件即为口径记录**（⭐ 落在我侧 `files/20-代码/`）<br>⚠️ 我们**也会去更新** `files/20-代码/FPGA侧答复-ESP32对接清单-20260923.md:234` 那处旧口径（⭐ 标"已被 2026-09-30 裁定取代：只针对流控"） |

📌 **裁定理由**：⭐ **我们事实上已经在回传了** ——
`calib.err` 的 6 类原因码 · `tare`/`span` 完成 · `at_done` —— ⭐ 这些**正是"数据回传"**，
⭐ 而且**没有提供任何背压**（⭐ 与你们的实现一致：⭐ FPGA 侧也不等 ESP32 的"忙"信号）。
⇒ ⭐ **"回传数据" 与 "提供背压" 本来就是两件事** ⇒ ✅ **拆开是准确的**。

---

## 五、Q4 答复：⚠️ **选 A（只回传稀疏事件）** —— ⭐ 而且我们的溢出【是可见的】

| 项 | ⭐ 我们的答复 |
|---|---|
| **选哪个** | ⭐ **A. 丢** —— ⭐ **只回传稀疏事件**，⭐ **内容避开发热路径**（⛔ 不在每个音符事件上回一条） |
| **为什么不用 B（FIFO）** | ⚠️ 我们**其实已经有 FIFO 了**：`rtl/w3c/uart_tx_fifo.v`（**`DEPTH=8`**），⭐ 回包经它入队 ⇒ ⭐ **单拍请求也不丢**（⭐ 这正是 `K-126` 的修法） |
| ⭐ **关键：我们不静默丢** | ⭐ FIFO 有 **`ovf`（溢出标志）＋ `drop_cnt`（丢弃计数）** 两个输出，⭐ 且 `tb_uart_tx_fifo` 里有判据：**"推 9 个（深度 8）⇒ ovf=1, drop_cnt=1，前 8 个仍全部发出"** ✅<br>⇒ ⭐ **满足你们 §4.3 方案 B 要求的"溢出可见"** ✅ |
| **要不要背压（C）** | ⭐ **本轮不做**（⭐ 与 Q3 裁定一致：⛔ 不提供流控）⇒ ⚠️ 我们**自己按节流发**（稀疏事件天然满足"任意两事件间隔 ≫ 10 ms"） |

> 📌 **我们接受你们 §4.1 的更正**：⭐ 两个方向的瓶颈在 **BLE 空口 ＋ ESP32 CPU**，⛔ **不是 UART 波特率的"对半分"** ——
> ⭐ 这一条对我们尤其重要：⚠️ 我们**不会**以为"我们只发一点点，所以对曲谱没影响" ✅

---

## 六、Q5 答复：⭐ **"离散事件"这一批【已经实现了】**，⚠️ 只缺"真进度百分比"

| 你们的候选 | ⭐ 我们的状态 |
|---|---|
| ⭐ **`calib.err`** | ✅⭐ **已实现**：`S` 的 6 类原因码（`!`/`w`/`o`/`b`/`?`/`0`/`1`/`2`），⭐ **上板实测已出现 `1`/`2`**（2026-09-30 21:53） |
| ⭐ **`calib.busy`** | ⚠️ **有信号但没回传**（`busy` 未接出）⇒ ⭐ 想做可以做 |
| ⚠️ **真"进度百分比"** | 🔴 **做不了** —— `calib` **没有进度输出**（⭐ 只有 `busy`/`err`）⇒ ⚠️ **必须新增信号**（⭐ 你们说得对）<br>⭐ 折中：⭐ **轴号序列本身就是进度**（`S` 会逐轴回轴号，⭐ 数到第几个轴号 = 进度）✅ |
| ⭐ **`evt_underrun_o`** | ⚠️ 现状：`play_seq` **未例化**（⭐ `K-145`：曲谱/tempo 链是**死链**）⇒ 🔴 **`evt_underrun_o` 现在不可观测**（⭐ 观测窗口也无从谈起） |
| ⭐ **音符 / 音乐事件** | 🔴 **完全空白**（⭐ 与你们一致）⇒ ⚠️ **本轮不做** |

### ⭐⭐ 所以你们的建议「先做离散事件」—— ⭐ **我们已经做完了第 ① 步**

⭐ 你们建议的 ① = **"请求操作 / 完成 / 错误"** ⇒ ⭐ 对应我们的：
**`t`/`s`/`x`（请求受理）· `T`/`.`/`D`（完成）· 6 类原因码（错误）** ✅

⇒ ⭐ **FPGA 侧剩下的活只有一件**：**把这些字节【再发一份】到新的 ESP32 那一路 UART**（⭐ 见 §二 的架构）。
⭐ 这**不是新功能**，⭐ 是**改接线/复制一路发送通路** —— ⚠️ 风险与工作量都远小于"从零写 `uart_tx`"。

---

## 七、⭐⭐ 本轮交付物 = **接口约定**（⚠️ RTL 实现【暂缓】）

> ⭐ **用户 2026-09-30 深夜明确**：*"不用着急写 FPGA 侧的代码，⭐ **约定一下就可以**"*
> ⇒ ⭐ **本节就是约定** —— ⛔ 不含任何一方要改的代码。

### 7.1 ⭐⭐ 物理层约定

| 项 | ⭐ 约定 |
|---|---|
| **J9 那一路**（`D14` / `D15`） | ⭐ **保持现状不变** —— 调试 / 命令（`calib_cmd`）/ 串口屏（`uart_ui`）/ 诊断包 `P`/`N`/`V` |
| **ESP32 那一路**（**新开**：`G22` = ESP32→FPGA · `G21` = FPGA→ESP32） | ⭐ **专用** —— ① 收：曲谱事件帧（`0xA5` 帧，⭐ 与你们现有的下行格式同构）② 发：**事件回传**（⭐ 见 7.2 / 7.3） |
| **波特率** | ⭐ **500000**（⭐ 8N1，⛔ 无流控）—— ⭐ 与我们全侧一致（`BAUD_DIV=100` ⇒ 50 MHz ÷ 100 **整除、零误差**） |
| **电平 / bank** | ⚠️ **待核**（⭐ `PMOD0` 落在哪个 bank ⇒ 是 `LVCMOS33` 还是别的，⭐ 必须**逐个核 bank**，⛔ 不照抄上一个引脚） |
| **空闲电平** | ⭐ **空闲高**（⭐ 我们 `uart_tx` 复位后即空闲高，⭐ 有仿真判据"reset returns tx to the idle HIGH level" ✅） |
| **接线** | ⚠️ **交叉**：ESP32 `GPIO17`(TX) → FPGA `G22`(新 rx)；FPGA `G21`(新 tx) → ESP32 `GPIO18`(RX)；⭐ **GND 必须共地** |

### 7.2 ⭐⭐ 上行（FPGA → ESP32）内容约定

> ⭐ **关键设计决定**：⭐ **因为 ESP32 是【单独一路 UART】，⛔ 它不需要和 `J9` 那路争字符空间**
> ⇒ ⭐ **这一路可以有【自己的协议】**，⭐ **且可以更大胆**（⭐ 建议用**带帧头的帧**，⛔ 不用逐个 ASCII 字母 —— 理由见下）。

| # | 内容 | ⭐ 约定 |
|---|---|---|
| **①** | ⭐ **标定事件**（⭐ 已有信号，⭐ 只是现在发在 `J9`） | ⭐ **原样再发一份**：`t`/`s`/`x` · 轴号 `0`~`F` · `.` · `D` · `T` · **6 类原因码** `!`/`w`/`o`/`b`/`?`/`0`/`1`/`2`<br>⚠️ **已知坑（⭐ 必须写清）**：`0`/`1`/`2` **既是原因码又是轴号字符** ⇒ ⭐ **我们的解析纪律 = "拒绝字节总是紧跟在【一个轴号之后**】"（`top.v:2005`）⇒ ⭐ 请你们也按**位置**解析，⛔ 不按字母表 |
| **②** | ⭐ **looper / 事件回传**（⭐ 见 7.3） | ⭐ **建议用带帧头的帧**（⭐ 与你们下行的 `0xA5` 帧同构 ⇒ ⭐ **两端复用同一套解析思路**） |

**⭐ 为什么建议 ② 用帧、而不是继续用 ASCII 单字节流**（⭐ 三条理由）：

```
① ⭐ 上游是【真 UART】⇒ 字节边界天然保留 ⇒ ⛔ 不需要下行那条"9N 对齐"纪律（⭐ 同意你们 §4.4-1）
② ⭐ looper 事件带【数值】（轴号 / 力度 / 时刻 / 层号）⇒ ASCII 单字节装不下
   ⚠️ 而若硬塞进 ASCII，就必须再引入转义/分隔符 ⇒ 🔴 又把"字母冲突"问题引回来
③ ⭐ 单独一路 ⇒ ⛔ 不会与 J9 的调试判据冲突（⭐ 我们那套 `T0~T8` 判据读的是 J9）
```

### 7.3 ⭐⭐ `looper` 联动的接口约定（⭐ 用户提出的新用途）

> ⭐ 用户 2026-09-30："这个是 FPGA 返回事件文件给 ESP32 的，⭐ **应该可以和 loop 联动**"

**⭐ 我们这一侧现成可用的信号**（⭐ 已核实，⛔ 不是许诺）：

| 信号 | 现状 | ⭐ 能不能回传 |
|---|---|---|
| `looper` 的**重放事件**（`play_valid_o` / `play_kind_o` / axis / vel） | ✅ **存在**（`rtl/w3c/looper.v`） | ⭐ **能**（⭐⭐ 这就是"looper 联动"最自然的内容：⭐ **把 loop 正在弹的事件实时回传**） |
| `looper` 的 `evt_cnt` / `full` / `drop` / `overflow` | ⚠️ **有输出，但在 `top.v` 里【无消费者】**⇒ 🔴 **会被综合 sweep**（⭐ 与 `K-106` 可观测纪律相冲） | ⭐ **能，但要先接出消费者**（⭐ 这是实现期的事） |
| `seq_arb` 的**分源计数**（live / score / demo） | ✅ **存在**（`tb_seq_arb` 判据"三个分源计数都真的在数" ✅） | ⭐ **能**（⭐ "现在是谁在发"一眼可见） |
| `evt_merge` 的 `collision` / `merged` / `drop` / `overflow` | ✅ 存在（`tb_seq_arb` 覆盖） | ⭐ **能** |
| ⚠️ `evt_underrun_o`（`play_seq`） | 🔴 **不可用** —— `play_seq` **未例化**（`K-145`，曲谱/tempo 是**死链**） | ⛔ **暂时不能** |

**⭐⭐ 用户 2026-09-30 深夜的需求已经明确（⭐ 所以这一节不再是"待定"）**：

> ⭐ 用户原话：*"这个是实现 **FPGA 乐曲回传**的，也就是**回到电脑上能逆向回 MIDI**。MIDI 有力度吗？"*

⇒ ⭐ **选 L1（音符事件）**，⭐ **而且目标很具体：⭐ 回传的数据要能【在 PC 上逆向还原成 MIDI】**。

### ⭐⭐ 先回答那个问题：⭐ **MIDI 有力度，而且有【两个】**

| MIDI 消息 | 字节 | ⭐ 力度 |
|---|---|---|
| **Note On** `0x9n` | `note`(0–127) + **`velocity`(0–127)** | ⭐ **按下力度** |
| **Note Off** `0x8n` | `note` + **`release velocity`(0–127)** | ⭐ **松开力度**（⚠️ 多数设备写 0 或 64，**基本没人用**） |
| ⚠️ 特例 | `velocity = 0` 的 Note On **等价于 Note Off** | ⭐ 标准约定 |

⭐ **我们这边的料是够的**：`vel` 是 **8 位（0–255）** ⇒ ⭐ **÷2 缩放到 0–127**；
⭐⭐ 而 `looper` **连"本音峰值力度"都记着**（`vel_max_r`，⭐ 它把 `note_off` 的力度换成"本次按键的峰值"）
⇒ ⭐ **release velocity 那一栏我们也有真实值可填** ✅

### ⭐⭐ 为"逆向回 MIDI"设计的【上行帧约定草案】

⭐ **建议与你们下行的 `0xA5` 帧同构**（⭐ 两端复用同一套解析思路）：

```
⭐ 帧 = 【帧头 0xA5】【类型 1B】【载荷】【(可选)校验 1B】

类型 0x01  NOTE_ON   载荷: tick(4B) + axis(1B) + phase_inc(4B) + vel(1B)
类型 0x02  NOTE_OFF  载荷: tick(4B) + axis(1B) + phase_inc(4B) + vel(1B)   ← ⭐ vel = 本音峰值力度
类型 0x03  CALIB     载荷: 事件字节（t / s / x / T / . / D / 6 类原因码）
类型 0x04  LOOPER    载荷: 状态位 + 层号 + 事件数 + 溢出标志
```

| 字段 | ⭐ 为什么这么定 |
|---|---|
| ⭐ **`tick`（4B 自由运行计数器）** | ⭐ MIDI 需要 Δt ⇒ ⭐ PC 侧用相邻 `tick` 之差算 Δt，再映射到 tempo。⚠️ **`tick` 计数器是新增的**，⭐ 但它**极便宜**（一个 32 位计数器） |
| ⭐ **`phase_inc`（4B，⛔ 不是音符号）** | ⚠️ **对数在 FPGA 上太贵**（要 LUT/DSP ＋ 迭代）⇒ ⭐ **FPGA 只回传相位增量，⭐ 由 PC/ESP32 侧反算音符号**（`note = 69 + 12·log₂(f/440)`，⭐ `f = phase_inc × fs / 2³²`） |
| ⭐ **`axis`（1B）** | ⭐ 让 PC 侧知道"是哪个物理键" |
| ⚠️ **`axis → 音高` 是张表**（`axis_map.kb_inc[]`），⭐ **而且变调/换模式会改它** | ⭐ **要么 PC 侧硬编码同一张表，⭐ 要么约定一条"表同步"命令**（⭐ 我们建议后者，⛔ 否则两边表必然漂） |
| ⭐ **`vel`（1B）** | ⭐ 映射到 MIDI velocity（⭐ `/2`） |

### ✅ ⭐ 带宽够不够？⭐ **绰绰有余**（⭐ 这条是好消息）

```
⭐ 弹奏速率 ≈ 每秒 10~30 个事件（note_on + note_off）
⭐ 每帧 ≈ 12 字节 ⇒ ⭐ ≈ 360 B/s
⭐ 反向通路上限（你们 §2.3 给的）≈ 514 B / 10 ms ≈ 51 KB/s
⇒ ⭐ 占用不到 1% ⇒ ⭐ **MIDI 回传的带宽【不是问题】** ✅
⚠️ 唯一要小心的是：⭐ 若把 laper 重放的密集事件也全回传 ⇒ ⚠️ 才需要限速/摘要
```

### ⚠️ 其余两个选项（⭐ 记录备查，⛔ 本轮不做）

| 选项 | ⭐ 含义 | 状态 |
|---|---|---|
| **L2** | 回传 looper **状态**（录制中/播放中/层号/事件数/溢出） | ⭐ **建议一起带上**（⭐ 就是上面 `类型 0x04`，⭐ 稀疏、零风险，⭐ 且复用 §五 的"离散事件"判据） |
| **L3** | ⭐ **双向**：ESP32 也能**控制** looper（录/停/播/清/切层） | ⏸ **本轮不做** —— ⚠️ 现状 `R`/`L`/`C` 命令走 `J9`，⭐ 若要在 ESP32 那路控制 ⇒ ⭐ 要把命令也接一份过来 |

### 7.4 ⏸ 实现（⭐ **暂缓** —— ⭐ 等约定冻结 ＋ 现有 2 个红 tb 清掉之后）

| # | 做什么 | 判据 |
|---|---|---|
| **1** | `constr/top.cst`：分配 **`G22` = 新 `uart_rx_esp`** / **`G21` = 新 `uart_tx_esp`**（⚠️ `PMOD0`·`BANK` 待核） | 引脚不冲突 · PnR 0/0 |
| **2** | `top.v`：新增一路 `uart_rx` ＋ `uart_tx`（＋ `uart_tx_fifo`）<br>· 收侧：`evt_uart_rx`（`0xA5` 帧）迁过来<br>· 发侧：标定事件**再发一份**（⭐ 保 `J9` 行为不变） | 聚焦 tb 全绿 · 回归「通过数 == 共数」· PnR 0/0 且余量 ≥3% <br>⚠️ **2026-10-01 更正**：⭐ 门槛已由 **5% 降到 3%**（⭐ 用户裁定）⇒ 判据改为 **`Fmax ≥ 51.5 MHz`**。<br>⭐ 理由：⭐ 5% 的原始依据已被用户撤回（⭐ 那次 0.18% 上板异常是**代码 bug**，⛔ 非时序问题）；<br>⭐ 当前实测 `52.372 MHz`（+4.744%）⭐ 在 3% 下通过。⚠️ **新增 UART 后必须重测并对比**。 |
| **3** | 接出 looper 的状态/事件消费者（⚠️ 否则会被 sweep） | 判据可红 |
| **4** | 新增 tb："ESP32 那一路与 `J9` **互不干扰**"（⭐ 含非空洞性） | 判据可红 |
| **5** | ⚠️ 更新旧口径：`files/20-代码/FPGA侧答复-ESP32对接清单-20260923.md:234` 标"已被 2026-09-30 裁定取代" | 文档与裁定一致 |

⚠️ **门序**（⭐ 本项目硬规则）：综合门 ⇒ 聚焦 tb ⇒ **PnR** ⇒ 全量回归 ⇒ 归档四件套 ⇒ 上板 —— ⛔ 不许跳步。
⚠️ **当前占用 79.5%** ⇒ ⭐ 新增一路 UART ＋ looper 消费者后**必须重核余量**（⭐ 门槛 ≥3%）。
> ⚠️ **2026-10-01 更正**：⭐ 门槛已由 **5% 降到 3%**（⭐ 用户裁定）⇒ 判据改为 **`Fmax ≥ 51.5 MHz`**。
> ⭐ 理由：⭐ 5% 的原始依据已被用户撤回（⭐ 那次 0.18% 上板异常是**代码 bug**，⛔ 非时序问题）；
> ⭐ 当前实测 `52.372 MHz`（+4.744%）⭐ 在 3% 下通过。⚠️ **新增 UART 后必须重测并对比**。

---

## 八、⭐ 对你们 §五 验收建议的回应

| 你们的判据 | ⭐ 我们的回应 |
|---|---|
| **1. 长度相等** | ✅ 采纳 |
| ⭐ **2. 逐字节相等（递增图样）** | ✅⭐ **采纳，且这是最强的一条** —— ⭐ 与我们 `tb` 里"回环比对"同一思路 |
| **3. ESP32 侧对账（`uart_rx=` vs PC 收到）** | ✅ 采纳（⭐ 用你们的 `read_log.py`） |
| **4. `fail=0`** | ✅ 采纳 |
| **5. 9N 整倍数** | ⚠️ **不适用**（⭐ 我们**不承诺 9N**，见 Q2-a） |
| ⭐ **6. 空闲电平（防 `M111` 那类幻影帧）** | ✅⭐ 采纳 —— ⭐ 而且我们**已有**这条仿真判据（`tb_uart_tx`："reset returns tx to the idle HIGH level" ✅ PASS）⇒ ⭐ **上板再确认一次** |

⚠️ **一处必须事先说清**（⭐ 免得验收时误判）：⭐ **我们的回包是【事件驱动】的**，⛔ 不是"上电就吐 21 字节"。
⇒ ⭐ 你们的 §5.2 测试 ① 建议改成：**上电后发一个会触发回包的命令**（⭐ 例如发 `T` ⇒ 应回 `t`，随后回 `T`），
⭐ 而不是"上电后自动发 21 字节"（⭐ 我们的设计里**没有**这种自发流；⭐ 若要，得专门加一个自检模式 —— ⚠️ 那是新增）。

---

## 九、⭐ 边界确认（⭐ 与你们 §六 一致）

| # | 说明 |
|---|---|
| **1** | ✅ **我们⛔ 不改你们 `FPGA2026-esp32` 里的任何东西** —— ⭐ 本答复写在**我们自己的** `files/20-代码/` |
| **2** | ⭐ 本答复**是回话**，⛔ 不是变更单 |
| **3** | ⭐ **Q3 的矛盾已裁定**（⭐ 见 §四）—— ⚠️ 这一条**是本次唯一需要用户拍板的**，已拍板 |
| **4** | ⚠️ 上行格式（Q2）⭐ 我们**只承诺"现状如此"**，⛔ 不承诺"以后不改" |
| **5** | ⭐ 你们 §1.2 那 21 字节**只证明 ESP32 侧** —— ⭐ 我们**同意**，⭐ 且**现在补上另一侧的证据**（§〇 那张表） |
| **6** | ✅ 你们 §4.1 的更正我们接受（⭐ 见 §五 的引注） |
| **7** | ⭐ 我们**没有**用你们仓库的 `rtl/` 快照做判断 —— ⭐ 全部结论来自 `FPGA2026-deliver` |

---

## 附 · 本答复的证据索引（⭐ 便于你们复核）

**我们的代码**
`rtl/w3c/uart_tx.v`（18,177 B，2026-09-30 14:33:55）· `rtl/w3c/uart_tx_fifo.v`（14,132 B）
`rtl/top.v:918-926`（`u_uart_tx`，`BAUD_DIV=100`，`.tx_o → D15`）
`rtl/top.v:813-817`（`u_evt_uart_rx`，现在挂在**同一条** `uart_rx` 上）
`rtl/top.v:2069`（`assign tx_req = rep_req | pp_push | vp_push | np_push`）
`rtl/top.v:2023-2032`（6 类原因码的原始映射）
`constr/top.cst:137`（⭐ `PMOD0` 含 `G21`/`G22` ⇒ **当前未分配**）· `:364`/`:366`（`uart_rx=D14` / `uart_tx=D15`）

**我们的证据**
`sim/evidence/tb_uart_tx.log`（PASS，含 reset 空闲高）·
`sim/evidence/tb_uart_tx_fifo.log`（PASS，含 `ovf`/`drop_cnt`）·
`sim/evidence/tb_calib_span_err.log`（⭐ **红**，⚠️ 已立案）·
`build/bitstreams/AN_drum_seldrum1_FA47FB0.meta.txt`（⭐ 本版位流：0/0 · **Fmax 53.821 MHz（+7.64%）**）

**我们的新文档**
`bringup/18-上板验证卡-功能修复-20260930深夜.md`（⭐ 现象速查 ＋ T0~T8 判据）
`files/00-总览/未推进项与后续计划-20260930深夜.md`（⭐ bug 全景 ＋ P0~P3）

**现场实测**
2026-09-30 21:53 · ⭐ **FPGA → 串口 → PC 反向通路逐字节到达**（用户现场记录：
`s`＋轴号`0` / 原因码 `1`/`2` / `.` / `T`）⇒ ⭐ **反向通路本体已通**（⭐ 用的是 `J9` 那一路）
