hokuu1102/Gowin2026-PolySynth/files/20-代码/今晚任务书-20260930.md

# 🌙 今晚任务书（2026-09-30 → 10-01）

> **⭐ 本文件是"自动驾驶"的【唯一状态源】** —— ⚠️ 每轮开工先读它，⛔ 不靠对话记忆。
> **工作目录**：`C:\Users\hokuu\Desktop\FPGA\FPGA2026-esp32`
> **范围**：⭐ **只动 `esp32/` 与 `files/`** —— ⛔ **不碰 `rtl/` `constr/` `tb/` `sim/`**
> **建立**：2026-09-30 夜
> **驱动**：⭐ `create_goal`（`max_goal_rounds=40`）⇒ ⭐ 每轮自动续跑，⛔ 不需要用户 prompt

---

## 〇、⭐⭐ 怎么读这份文件（⭐ 每轮开工照做）

```
① 从 §三 的任务表里，找第一个【状态 = ⏳ 可做】的行
② 做它：实现 → 编译 → 实测或离线自检 → 看判据
③ ⭐ 回来把该行改成 ✅（附证据）或 🔴 阻塞（附原因）
④ 本地 commit（⛔ 不 push）
⑤ 没有 ⏳ 可做项了 ⇒ 把 §三 表头改成「今晚可做的已做完」并列出剩余项
```

⚠️ **⛔ 不要跳过判据** —— ⭐ **判据是唯一能证明"真的做完了"的东西**。
⚠️ **⛔ 不许把中间态留在树里** —— ⭐ **任何时刻树都要能编译**。

---

## 一、⭐⭐ 铁律（⭐ 违反任何一条 = 今晚的活白做）

| # | 🔴 铁律 |
|---|---|
| **1** | ⛔ **不 push** —— ⭐ 本地 commit 不限次数；push 必须用户明确同意 |
| **2** | ⛔ **不碰 `rtl/` `constr/` `tb/` `sim/`**（⭐ 属 FPGA 线，另一会话） |
| **3** | ⛔ **一次只改一个变量** —— ⚠️ 同时改两处，出了错分不清是谁 |
| **4** | ⭐ **每个判据必须先确认【能失败】**（非空洞性）—— ⚠️ 否则是假绿（`C83`） |
| **5** | ⭐ **改完必编译**（`idf.py build`）—— ⚠️ 零 error 零 warning 才算过 |
| **6** | ⚠️ **无硬件时⛔ 不许假装实测** —— ⭐ 只做能离线验证的，并**标明"未实测"** |
| **7** | 🔴 **端口会漂** —— ⛔ 不写死 `COM29`/`COM31`（⭐ 每次先查） |
| **8** | ⚠️ **烧录会清空池** —— ⭐ 实测前要重新灌数据 |
| **9** | ⚠️ **代理可能挂** —— ⭐ push/fetch 失败时用 `-c http.proxy=` 单次覆盖 |
| **10** | ⚠️ **`-D` 改了要删 `build/`**（⭐ CMake 缓存会粘住，见 `C99`/`C61`） |

---

## 二、⚠️ 已知的两个"自发工作"断点（⭐ 必须知道）

| # | 断点 | ⚠️ 后果 | ⭐ 对策 |
|---|---|---|---|
| **1** | ⭐ **轮次上限** `max_goal_rounds=40` | ⚠️ 用完就停 | ⭐ 任务书**落盘** ⇒ 用户下次说"继续"就能**无损续跑** |
| **2** | 🔴 **硬件依赖项** | ⚠️ 无板子/无接线就做不了 | ⭐ 任务表里**显式标注**哪些需要硬件 ⇒ ⭐ 无硬件时自动跳过 |

⚠️ **诚实说清**：⭐ **我无法在自己被停止后自行重启** —— ⚠️ 那是会话机制，⛔ 不是我能绕过的。
⭐ **我能保证的是**：⭐ **在轮次预算内不停手**，且⭐ **任何时刻被中断都能从任务书无损续跑**。

---

## 三、⭐⭐ 任务表（⭐ 按此顺序做，⛔ 不跳）

> ### ✅✅ **今晚【可做】的 5 项（任务 2/3/4/5/6）【全部完成】** —— 2026-09-30 夜
>
> | 任务 | ⭐ 结果 |
> |---|---|
> | **2** `uart_test` 回归 | ✅ 972 字节 / 序号 0..107 零缺口 |
> | **3** 全工具 selftest | ✅ 10/10 通过（⚠️ 查出 6 个工具无 selftest） |
> | **4** flash 16MB | ✅ `--flash_size 16MB` + 重烧后 E2E 全绿 |
> | **5** `esp32/bridge/` 500k | ✅ 三工程波特率一致 + 编译通过 |
> | **6** 文档审计 | ✅ 13 文件 / 42 处陈旧断言更正 |
>
> ⚠️ **剩余项全部【需要外部条件】** ⇒ ⭐ 见下方各行的阻塞原因（⛔ 不是没做）。
> 📌 **续跑方式**：⭐ 用户回来说"继续"即可 —— ⭐ 本文件就是**唯一状态源**。

| # | 任务 | ⭐ 状态 | 硬件? | 判据 |
|---|---|---|---|---|
| **1** | ⭐ **push 未推提交**（⚠️ 数字**易失** —— 🔴🔴 **2026-10-01 修正**：⚠️ 原文写「现已 6 个」+ `ahead/behind = 0 0` ⇒ 【两者都已过时】；⭐ 实测 `git status -sb` = `ahead 22`。⭐ **一律以 `git status -sb` 为准，⛔ 不写死**） | 🔴 **需用户同意** | — | ⭐ **以 `git status -sb` 的 `ahead N` 为准** |
| **2** | ⭐ **`uart_test` 诊断固件回归** | ✅ **完成**（2026-09-30 夜） | ⚠️ 需板 | ⭐ **972 字节 / 108 帧 / 序号 0..107 零缺口 / 帧头全 `0xA5`**<br>⭐ 与首次实测**完全一致**<br>⚠️ 测完已**烧回正式 `esp32/ble/` 固件**（`ring=0/163840` 为证） |
| **3** | ⭐ **全工具 `--selftest` 总检** | ✅ **完成**（2026-09-30 夜） | ✅ **纯离线** | ⭐ **10/10 退出码 0**<br>⚠️ **但 6 个工具【无 selftest】** ⇒ 见 §四 的发现 |
| **4** | ⭐ **`flash` 映像头 2MB → 16MB** | ✅ **完成**（2026-09-30 夜） | ⚠️ 需板验证 | ⭐ **`--flash_size 16MB`**（原 2MB）<br>⭐ 依据：实机 `Detected flash size: 16MB`<br>⭐ 分区表**未动**（仍 `partitions_singleapp`）<br>⭐ **重烧后板子正常 + E2E 全绿**（帧数 200/200、`sent=200`、退出码 0） |
| **5** | ⚠️ **`esp32/bridge/`(SPP) 波特率同步 500k** | ✅ **完成**（2026-09-30 夜） | ✅ 纯离线可验 | ⭐ **三个工程全 = 500000**<br>⭐ `esp32/bridge/` 编译通过（`0xa4b30`）<br>⚠️ **无法实测**（无初代 ESP32 板） |
| **6** | ⭐ **文档审计：ESP32 侧陈旧断言** | ✅ **完成**（2026-09-30 夜） | ✅ **纯离线** | ⭐ **共查出 7 类陈旧断言、更正 13 个 `.md`**<br>⚠️ **每条更正均带 `🔴🔴 2026-09-30 更正：` 前缀 + `file:line` 或实测值**<br>⭐ **未触碰** `rtl/` `constr/` `tb/` `sim/` 与任何 `.c`/`.h` |
| **7** | ⚠️ **串口屏 HMI 联调** | ✅✅ **已完成**（2026-10-01） | ✅ 屏已接 | ⭐ **屏上 6 栏全部跟着实际状态变**<br>🔴🔴 **2026-10-01 修正：⚠️ 原文写「🔴 需硬件 / 🔴 屏未接」⇒ 【已作废】**（`esp32/evidence/串口屏HMI验收报告-20261001.md`） |
| **8** | 🔴 **FPGA 端到端联调** | 🔴 **等 `G21`/`G22` 引脚分配** | 🔴🔴 **2026-10-01 修正：⚠️ 原文写「需 `uart_tx.v`」⇒ 【已作废】** —— ⭐ `rtl/w3c/uart_tx.v` **已存在且已在 `top.v:943` 例化**（⭐ 另补 `uart_tx_fifo` @ `:928`）；⭐ ESP32 侧反向链路**已实测打通**（2000 B round-trip 逐字节一致） | 按键起播真的出声 |
| **9** | ⚠️ **起播架构裁定** | ✅ **已裁定（2026-09-30）** | 🔴🔴 **2026-10-01 修正：⚠️ 原文写「🔴 等用户/FPGA 侧」⇒ 【已作废】** —— ⭐ 用户裁定 **Q1 = 走模式 B（ESP32 起播）**（`files/20-代码/用户裁定结果-20260930.md`），⭐ 并已落地 `CMD 0x03`/`0x04`（`ble_main.c:691`/`:696`） | ✅ 裁定单有答案 |
| **10** | ⚠️ **上行载荷格式定义** | 🔴 **等 FPGA 侧** | — | — |

---

## 四、⭐⭐ 各项的详细做法（⭐ 做到哪一项就看哪一节）

### 任务 2 —— `uart_test` 诊断固件回归

**为什么**：⭐ 本轮改了 `ble_config.h`（RX 缓冲 1026→8192）等，⚠️ **但 `uart_test` 是独立工程**，
⭐⭐ **它没被本轮改动影响** —— ⚠️ **但正因为独立，它是"UART 物理层"的**对照组**，
⭐ 值得复跑一次确认硬件链路本身没问题。

**做法**：
```powershell
cd esp32\uart_test
. "C:\Espressif\tools\Microsoft.v5.5.PowerShell_profile.ps1"
idf.py build
idf.py -p <ESP32口> flash
# ⭐ 然后：先开抓 COM31，再复位板子（⚠️ 顺序不能反，见 C103）
```

**判据**：⭐ 收到 **972 字节**、**序号 0..107 零缺口**、帧头全 `0xA5`

⚠️ **注意**：⭐ `uart_test` 的 `TEST_BAUD` 当前是 **500000**（⭐ 与正式固件一致）

---

### 任务 3 —— 全工具 `--selftest` 总检（⭐ 纯离线，最稳）

**为什么**：⭐ 本轮新增/改了 **5 个工具**，⚠️ 但**没有一次总检**。
⭐ 且 ⚠️ 工具是**验收的依赖** ⇒ 🔴 **工具坏了，验收结论就不可信**。

**做法**：逐个跑，记录退出码：
```
read_log.py            （无 selftest，用 --help）
uart_rx_check.py       --help
uart_timing_check.py   --help
pool_pace_check.py     --help
trigger_and_capture.py --help
send_frames.py         --selftest
send_frames_ble.py     --selftest
pool_math_check.py     （直接跑）
loopback_check.py      --selftest
e2e_accept.py          --selftest
```

**判据**：⭐ **全部退出码 0**（⚠️ 且 GBK 控制台下**不崩** —— ⭐ 这是 `C99`/`U85` 那类坑）

**⚠️ 顺带**：⭐ 若发现某个工具有 `--selftest` 是空的（⚠️ 永远绿），⭐ **记为发现**（⭐ 那是 `C83` 假绿）

#### ✅ 执行结果（2026-09-30 夜）—— ⭐ **10/10 通过**

⭐ 在 **GBK 控制台（代码页 936）**、**⛔ 不设 `PYTHONIOENCODING`** 的前提下跑：

| 工具 | ⭐ rc |
|---|---|
| `read_log.py` · `uart_rx_check.py` · `uart_timing_check.py` | **0** |
| `pool_pace_check.py` · `trigger_and_capture.py` | **0** |
| `send_frames.py` · `send_frames_ble.py` | **0** |
| `loopback_check.py` · `e2e_accept.py` · `pool_math_check.py` | **0** |

⇒ ⭐ **全部通过**，⛔ 无编码崩溃。

#### ⚠️ 但查出一个**真实的覆盖缺口**（⭐ 记为发现，⛔ 本轮不修）

🔴 **6 个工具【没有 `--selftest`】** ⇒ ⭐ 对它们，我只验到了 `--help`（argparse）：
```
pool_math_check.py · pool_pace_check.py · read_log.py
trigger_and_capture.py · uart_rx_check.py · uart_timing_check.py
```
⚠️ **而 `--help` 通过 ⛔ 不等于"能工作"**（⭐ 见 `C83` 假绿）。

⭐⭐ **尤其要紧的是**：⭐ 这 6 个里有 **4 个正是【验收用的工具】**
（`uart_rx_check` / `uart_timing_check` / `pool_pace_check` / `trigger_and_capture`）
⇒ 🔴 **它们的判据坏了，验收结论就不可信**。

⭐ **已确认非空洞的 4 个**：`send_frames` / `send_frames_ble` / `loopback_check` / `e2e_accept`
（⭐ selftest 体各约 **60 行**，且 `e2e` 的**实测能判红**——已单独验证）。

⚠️ **建议**（⭐ 留给后续）：给那 4 个验收工具补 `--selftest`，
⭐ 做法照 `e2e_accept.py`（⭐ **喂合成数据 + 断言正例绿 / 反例红**）。

---

### 任务 4 —— `flash` 映像头 2MB → 16MB

**为什么**：⚠️ 实机 flash 是 **16 MB**，⚠️ 但映像头写的是 **2 MB** ⇒
🔵 当前不阻塞（app 只用 0.79 MB），⚠️ **但将来放曲谱/字库会浪费 14 MB**。

**做法**：⭐ 改 `sdkconfig.defaults` 的 flash size 相关项 → ⭐ **删 `build/`** → 重编

**判据**：⭐ 构建日志里的 `--flash_size` 变成 **16MB**（⚠️ 现在显示 2MB）

⚠️ **风险**：⭐ 改 flash size 会**影响分区表** ⇒ ⚠️ **必须确认分区表仍放得下**（⭐ 看 `check_sizes.py` 输出）

---

### 任务 5 —— `esp32/bridge/`(SPP) 波特率同步

**为什么**：⚠️ 用户说"不管 SPP"，⚠️ 但**留着 1 Mbps 是个陷阱**：
🔴 将来谁碰 SPP，它会**与 FPGA 侧 500k 静默乱码**（⭐ 同 `C106` 那类）。

**做法**：⭐ `esp32/bridge/main/bridge_config.h` 的 `BRIDGE_BAUD` 改 **500000**
⚠️ **并加注释说明为什么**（⭐ 否则下一个人会改回去）

**判据**：⭐ 三个工程的波特率宏**全部 = 500000**（`ble` / `uart_test` / `bridge`）

⚠️ **注意**：⭐ 这个**无法实测**（没有初代 ESP32 板子）⇒ ⚠️ **只做静态一致性检查**

---

### 任务 6 —— 文档审计（⭐ 纯离线，价值高）

**为什么**：⭐ 本轮发现文档**多处陈旧**：
· `§4.4 不做反向通道` 与"要回传事件"**矛盾**（⚠️ 已记入对接单）
· 交接文档说"本地领先 2 个提交"（⚠️ 实际早已不同）
· `ESP32侧串口命令格式` 说反向通路"还没打通"（⚠️ **现已打通**）
· `esp32/bridge/README.md` 可能仍写 1 Mbps

**做法**：
1. ⭐ **逐个核对** ESP32 侧文档里"关于现状的断言" vs **实际代码/实测**
2. 🔴 **发现不符的，当场更正**（⭐ 保留"原→改"痕迹，⛔ 不删历史）
3. ⭐ 每条更正都要**有证据**（⭐ `file:line` 或实测数据）

**判据**：⭐ **每处更正都附证据**；⭐ 且**更正后文档内部不再自相矛盾**

#### ✅ 执行结果（2026-09-30 夜）—— ⭐ **13 个文件已更正**

| 🔴 陈旧断言（原文） | ✅ 更正为 | ⭐ 证据 |
|---|---|---|
| 波特率 `115200` / `1000000` / `1 Mbps` | ⭐ **`500000`** | `esp32/ble/main/ble_config.h` `BLE_BAUD 500000`·`esp32/uart_test/main/uart_test_main.c` `TEST_BAUD 500000`·`esp32/bridge/main/bridge_config.h` `BRIDGE_BAUD 500000` |
| 反向通路"**还没打通**" / "`uart_tx.v` 不存在 ⇒ 收不到" | ⭐ **已打通** | ⭐ **2000 字节 round-trip 逐字节一致**；`esp32/evidence/反向通路验收-ESP32侧-20260930.md` |
| `0xABF3` "**目前没用上**" / "**是废的**" | ⭐ **已有命令解析**（🔴🔴 **2026-10-01 更正**：⚠️ 原文写「`0x01` 清池 · `0x02` 状态」⇒ 🔴 **不完整** ⇒ ⭐ **现为七个命令**：`0x01` 清池 · `0x02` 状态 · ⭐ **`0x03` 起播** · ⭐ **`0x04` 停止** · ⭐ **`0x20` 屏探针** · ⭐ **`0x21` 原样 HMI 命令** · ⭐ **`0x22` 设曲名**）<br>🔴🔴 **2026-10-01 修正**：⚠️ 原文写「四个命令」+ 行号 `:606`/`:611`/`:629`/`:634` ⇒ ⭐ **实为 7 个**（`case 0x01`/`0x02`/`0x03`/`0x04`/`0x20`/`0x21`/`0x22` @ `esp32/ble/main/ble_main.c:659`/`673`/`691`/`696`/`712`/`724`/`753`），⛔ **原行号一个都不对** |
| `0xABF4` "**未使用**" / "从未被写" | ⭐ **已可读**（🔴 原 `ESP_GATT_AUTO_RSP` + `length=0` ⇒ **读回空**）<br>🔴🔴 **2026-10-01 更正**：⚠️ 原文「实测 `pool=0/18204 sent=0 ovf=0\|ring=0 u_drop=0/0`」⇒ 🔴 **旧的三组短格式，已作废** ⇒ ⭐ **现为八组**（`V1`/`pool`/`ring`/`ble`/`uart`/`hmi`/`frame`/`cmd`），🔴 **且是【拉取快照】**（⭐ 只有先发 `CMD 0x02` 才刷新，`cmd_report_status()` 调用点 @ `ble_main.c:675`）<br>🔴🔴 **2026-10-01 修正**：⚠️ 原文写「六组 / 约 221 字节」+ `ble_main.c:336` ⇒ ⭐ 实测格式串 **8 行**（`ble_main.c:419-435`）、函数在 `:362`、缓冲区 `s_val_stat[320]`（`gatt_svc.c:106`）；⛔ **字节数别写死**（210/221/261/264 四个数并存） | `esp32/tools/stat_read.py` |
| "本地领先远端 **2 个**" | ⭐ **以 `git status -sb` 为准**（⛔ 不写死数字） | ⭐ 易失数字 |
| ESP32 "**无上行缓冲**" / "一个字节都不缓冲" | ⭐ **`up_ring.c/.h`，160 KB PSRAM，蓄水/放水** | `esp32/ble/main/up_ring.c` |
| 按键脚 `GPIO0` | 🔴 **`GPIO6`** | `esp32/ble/main/ble_config.h` `BLE_BTN_GPIO 6` |

⚠️ **未确认项**：⭐ 在 `.md` 里**未找到把按键脚直接写成 `GPIO0` 的陈述** —— ⚠️ 见本任务结论的"开放问题"。
⭐ **另**：⭐ **`esp32/bridge/README.md` 确实仍写 1 Mbps**（⭐ 任务书预判正确）⇒ ✅ 已更正为 500 k。

⚠️ **重点排查**：
- 波特率相关（⭐ 1M vs 500k）
- "反向通路没打通"这类**状态性断言**
- "领先远端 N 个"这类**易失的**数字（⭐ 建议改成"以 `git status` 为准"）

#### 🔴🔴 2026-10-01 · ⭐ **第二轮审计**（⚠️ 第一轮漏的 + 当晚新改的）

> ⭐ 第一轮（2026-09-30 夜）修了 **13 个文件**；⚠️ 但**当晚之后代码又变了** ⇒ 🔴 **第一轮的结论自己变陈旧了**。
> ⭐ 第二轮补上的（⭐ 全部已就地更正）：

| # | 🔴 第一轮漏的 / 被后续改动作废的 | ✅ 第二轮更正 | ⭐ 证据 |
|---|---|---|---|
| **1** | `0xABF3` 只写 **`0x01`/`0x02`** | ⭐ **七个命令**（`0x01`/`0x02`/`0x03`/`0x04`/`0x20`/`0x21`/`0x22`）<br>🔴🔴 **2026-10-01 修正**：⚠️ 原文写「四个命令」+ 行号 `:606`/`:611`/`:629`/`:634` ⇒ ⭐ 实测 `case 0x01`/`0x02`/`0x03`/`0x04`/`0x20`/`0x21`/`0x22` @ `esp32/ble/main/ble_main.c:659`/`673`/`691`/`696`/`712`/`724`/`753`，⛔ **原行号一个都不对** |
| **2** | `0xABF4` 只有**三组短格式** | ⭐ **八组**（`V1`/`pool`/`ring`/`ble`/`uart`/`hmi`/`frame`/`cmd`）；🔴 **且是【拉取快照】**（⭐ 只有发 `CMD 0x02` 才刷新）<br>🔴🔴 **2026-10-01 修正**：⚠️ 原文写「六组 / 约 221 字节」⇒ ⭐ 实测格式串 **8 行**（`ble_main.c:419-435`），⛔ **字节数别写死**；⚠️ 原文写「⚠️ 无过期标记」⇒ 🔴 **已作废** —— ⭐ `V1` 行已带 `req=`/`up=` ⇒ ⭐ **陈旧可判定** | `cmd_report_status()` @ `ble_main.c:362`；`s_val_stat[320]` @ `gatt_svc.c:106` |
| **3** | `0xABF4` 属性写 **`NOTIFY`** | ⭐ **`READ`**（⭐ `ESP_GATT_PERM_READ` + `RSP_BY_APP`）⇒ 🔴 **固件不能 notify 它** | `esp32/ble/main/gatt_svc.c:180`~`:182` |
| **4** | ⚠️ **完全没提 WS2812 已关闭** | 🔴 **`WS2812_ENABLE=0` + `WS2812_CLEAR_ON_BOOT=1`** ⇒ ⭐ **永不点亮**（⭐ 用户「安全第一」） | `esp32/ble/main/ble_config.h:494` / `:502`；`files/20-代码/今晚任务书-20261001.md:38` |
| **5** | `flash` **2 MB** 映像头 | ⭐ **16 MB** | `esp32/ble/sdkconfig.defaults:40-41` |
| **6** | ⚠️ **完全没提** `esp32/tools/evt2midi/` · `stat_read.py` · `regress_live.py` | ⭐ 三个新工具已进 `esp32/README.md` §〇之二 | `esp32/tools/evt2midi/` · `esp32/tools/stat_read.py` · `esp32/tools/regress_live.py` |
| **7** | ⚠️ **完全没提** `--selftest` 覆盖 | ⭐ **8 个工具都有**（⚠️ `rec_upstream.py` 除外） | `files/20-代码/今晚任务书-20261001.md:67` |
| **8** | ⚠️ **完全没提**上行帧长**按类型不同** | ⭐ 音符类 **14 B**、表同步（`0x10`）**68 B** ⇒ 🔴 **⛔ 别用固定 14 B 切流** | `esp32/tools/evt2midi/frame_format.py` `FRAME_LEN_BY_TYPE` |
| **9** | 🔴 **本 worktree 的 `rtl/` 是旧快照**（⭐ 1710 行 vs main 3970 行）⇒ ⚠️ 它的 `top.v` 仍写 1 Mbps | ⭐ **核对波特率一律去 `FPGA2026`（main）worktree**：`FPGA2026/rtl/top.v:688` `.BAUD_DIV(100)` · `:715`/`:771`/`:815` `.BAUD(500_000)` | `git worktree list` |

---

## 五、⭐⭐ 今晚的"完成"定义

⭐ **做完 §三 里所有 `⏳ 可做` 项**（即 任务 **2/3/4/5/6**）⇒ ⭐ 今晚目标达成。

⚠️ **任务 1/7/8/9/10 做不了**（⭐ 需用户或硬件）⇒ ⭐ **在结论里明确列出**，⛔ 不算失败。

---

## 六、⚠️ 收尾要求（⭐ 每轮都要做）

| # | 动作 |
|---|---|
| **1** | ⭐ 更新本文件的任务表状态（⭐ 这是下一轮的依据） |
| **2** | ⭐ 本地 commit（⛔ 不 push） |
| **3** | ⭐ 确认 `git status` 干净（⚠️ 不留中间态） |
| **4** | ⭐ 确认 `idf.py build` 仍通过（⭐ 若改过固件） |

---

## 附 · 当前现场（⭐ 每轮开工核对）

| 项 | ⭐ 值 |
|---|---|
| 分支 | `feat/s3-ble` |
| 未推提交 | **1 个**（`db7d66d`） |
| 板子固件 | ⭐ 含 B 子集（`db7d66d`） |
| ESP32 口 | `COM29`（⚠️ 会漂） |
| USB-TTL 口 | `COM31`（⚠️ 会漂） |
| 波特率 | ⭐ **500000**（`ble` / `uart_test`） |
| ⭐ **最近一次实测** | ⭐ **e2e 全部通过**（200 帧、`rate=1919`、退出码 0） |

**关联文档**
`files/20-代码/ESP32侧工作计划-20260930.md`（⭐ 分类版）·
`files/20-代码/ESP32侧详细执行计划-20260930.md`（⭐ 5 步详情）·
`files/20-代码/矛盾裁定单-方案3与模式B-20260930.md`（🔴 阻塞项 9）·
`files/20-代码/反向通路对接单-给FPGA侧-20260930.md`（⚠️ 待 FPGA 侧答）
