hokuu1102/Gowin2026-PolySynth/files/20-代码/今晚任务书-20261001.md

# 🌙 今晚任务书（2026-10-01 夜）—— 自主续跑

> **⭐ 本文件是"自动驾驶"的【唯一状态源】** —— ⚠️ 每轮开工先读它，⛔ 不靠对话记忆。
> **工作目录**：`C:\Users\hokuu\Desktop\FPGA\FPGA2026-esp32`
> **范围**：⭐ **只动 `esp32/` 与 `files/`** —— ⛔ **不碰 `rtl/` `constr/` `tb/` `sim/`**
> **驱动**：⭐ `create_goal`（⭐ 自动续跑）
> **上一轮**：`files/20-代码/今晚任务书-20260930.md`（⭐ 5 项已全做完）

---

## 〇、⭐⭐ 怎么读这份文件（⭐ 每轮开工照做）

```
① 从 §三 找第一个【⏳ 可做】的行
② 做它：实现 → 编译 → 实测/自检 → 看判据
③ ⭐ 回来把该行改成 ✅（附证据）或 🔴 阻塞（附原因）
④ 本地 commit（⛔ 不 push，⭐ 除经验库满 10 条）
⑤ 没有 ⏳ 了 ⇒ 标「今晚可做的已做完」+ 列出剩余项与阻塞原因
```

⚠️ **⛔ 不许跳过判据** —— ⭐ **判据是唯一能证明"真做完了"的东西**。
⚠️ **⛔ 不许把中间态留在树里** —— ⭐ **任何时刻树都要能编译**。

---

## 一、⭐⭐ 铁律

| # | 🔴 铁律 |
|---|---|
| **1** | ⛔ **不 push**（⭐ 例外：经验库满 10 条自动推）—— ⚠️ **本轮用户已同意推过一次，⭐ 之后仍要逐次问** |
| **2** | ⛔ **不碰 `rtl/` `constr/` `tb/` `sim/`** |
| **3** | ⛔ **一次只改一个变量** |
| **4** | ⭐ **每个判据必须先确认【能失败】**（非空洞性）—— ⚠️ 否则是假绿（`C83`） |
| **5** | ⭐ **改完必编译**，零 error 零 warning |
| **6** | ⚠️ **无硬件时⛔ 不许假装实测** —— ⭐ 标明"未实测" |
| **7** | 🔴 **端口会漂** —— ⛔ 不写死 `COM29`/`COM31` |
| **8** | ⚠️ **烧录会清空池** —— ⭐ 实测前要重新灌数据 |
| **9** | 🔴 **灯保持关闭**（⭐ 用户 2026-10-01："安全第一"）—— ⛔ **不要重新打开 WS2812 指示** |
| **10** | ⚠️ **`-D` 改了要删 `build/`**（⭐ CMake 缓存会粘住，`C99`/`C61`） |

### ⭐ 本轮的等待纪律（⭐ 用户明确授权）

> ⭐ 用户 2026-10-01：「**可以在没有并行任务的时候 `wait: True`**」
⇒ ⭐ **允许**：⭐ 当**确实没有可并行的活**时，对长任务用 `wait: true`（⛔ 不必强行找活干）
⚠️ **但**：⭐ **有可并行的活时，仍然并行做**（⭐ 不要用"我在等"当借口）

---

## 二、⭐⭐ 现场（⭐ 每轮开工核对）

| 项 | ⭐ 值 |
|---|---|
| 分支 | `feat/s3-ble` |
| 远端 | ✅ **已同步**（`f1afda1`，`0 0`） |
| 板子固件 | ⭐ 含 WS2812 关闭 + CMD 命令集 |
| ⭐ **硬件** | ✅ **COM29（ESP32）+ COM31（CH340）都在** |
| 波特率 | ⭐ **500000**（三工程一致） |
| ⭐ **灯** | 🔴 **关闭状态**（⭐ 保持） |
| ⭐ 上一轮成果 | CMD 命令集 · 蓄水/放水缓冲 · 一键验收 · evt2midi 工具链 |

---

## 三、⭐⭐ 任务表（⭐ 按顺序做）

> ## ✅✅ **今晚【可做】的 6 项（任务 1~6）【全部完成】** —— 2026-10-01 夜
>
> | 任务 | ⭐ 结果 |
> |---|---|
> | **1** 6 个工具补自检 | ✅ 6/6 rc=0 · ⭐ **变异测试 22/22 判红** |
> | **2** STAT 扩展成完整状态 | ✅ 读回 26 字段 · 修 append→replace<br>🔴🔴 **2026-10-01 修正**：⚠️ 原写「六组 / 221 B」⇒ ⭐ 实测格式串 **8 行**（`ble_main.c:419-435`），⛔ 字节数别写死（210/221/261/264 四个数并存） |
> | **3** 表同步帧解析（⭐ **上位机侧**） | ✅ 帧长按类型 · ⭐ **ESP32 侧零改动**<br>🔴🔴 **2026-10-01 修正**：⚠️ 本行标题原写「CMD 表同步命令（`0x10`）」⇒ 🔴 **`0xABF3` 的 `0x10` 命令【未实现】**（⭐ `esp32/ble/main/ble_main.c` 里**没有** `case 0x10`）—— ✅ 完成的只是 **evt2midi 侧解析** |
> | **4** 帧格式抽模块 | ✅ `frame_format.py` = 唯一定义处 |
> | **5** 全回归复跑 | ✅ **六项全过**（含真机 CMD + 上行） |
> | **6** 文档审计第二轮 | ✅ 18 文件 · ⭐ 并修 9 处**行号漂移** |
> | **附** 额外两件 | ✅ `rec_upstream` 自检 · `selftest_all.py` · C115 第二层 |
>
> ⚠️ **剩余项全部【需要外部条件】**（⭐ 需接线 / 等 FPGA 侧）⇒ ⭐ **见下表阻塞原因**，⛔ 不是没做。
> 📌 **续跑**：⭐ 用户回来说"继续"即可 —— ⭐ 本文件就是**唯一状态源**。

| # | 任务 | ⭐ 状态 | 硬件? | 判据 |
|---|---|---|---|---|
| **1** | ⭐⭐ **给 6 个验收工具补 `--selftest`** | ✅ **完成**（2026-10-01 夜） | ✅ 纯离线 | ⭐ **6/6 全部 rc=0、RED=0**<br>`uart_rx_check` 18 · `pool_pace_check` 21 · `pool_math_check` 20<br>`uart_timing_check` 24 · `trigger_and_capture` 34 · `read_log` 35<br>⭐⭐ **非空洞性用【变异测试】证明：22/22 变异体都判红**（⛔ 不是"我断言它非空洞"）<br>⚠️ 已诚实标注未覆盖项：`_stamp_at()` 是 `main()` 内闭包，取不到 |
| **2** | ⭐ **`0xABF4`(STAT) 扩展成完整状态** | ✅ **完成**（2026-10-01 夜） | ⚠️ 需板 | ⭐ **读回 / 26 字段 / 8 行** ✅（🔴🔴 **2026-10-01 修正**：⚠️ 原写「221 字节 / 六组」⇒ ⭐ 实测格式串 **8 行**（`ble_main.c:419-435`）；⛔ **字节数别写死** —— 210/221/261/264 四个数在工程里并存）<br>⭐ 顺带修一个真 bug：`gatt_set_stat` 是**追加**应为**替换**<br>（连发 3 次 0x02 ⇒ 仍只有 1 份完整状态，已验证）<br>⭐ 新增 `stat_read.py`（11 项自检，⭐ 抓出我自己两个 bug） |
| **3** | ⭐ **表同步帧解析**（⚠️ **不是** `0xABF3` 的 CMD `0x10`） | ⚠️ **部分完成**（2026-10-01 夜） | ✅ 纯离线可验 | 🔴🔴 **2026-10-01 修正：⚠️ 原文标题写「CMD 表同步命令（`0x10`）」并标 ✅ 完成 ⇒ 【会误导接手人】** —— ⭐ **实测 `ble_main.c` 里没有 `case 0x10`**（⭐ CMD 实为 `0x01`/`0x02`/`0x03`/`0x04`/`0x20`/`0x21`/`0x22` @ `:659`/`673`/`691`/`696`/`712`/`724`/`753`）⇒ 🔴 **`0xABF3` 的"请求表同步"命令【未实现】**
⭐ **实际完成的是【上位机侧】**（⭐ 本行原文自己就写了"ESP32 侧零改动"）：`esp32/tools/evt2midi/frame_format.py` 的 `FRAME_LEN_BY_TYPE`（`T_TABLESYNC: 68`，`:68-74`）＋ 表帧解析
⚠️ **待办仍在**：`0xABF3` 加 `0x10`（⭐ 见本文件 §任务 3 做法第 1 条，`:162`）<br>⭐ **帧长按类型取**（`0x10` = 68 B，音符 = 14 B）<br>🔴 若不按类型取 ⇒ 68 B 被切成 4 个假帧 + 4 残留 ⇒ **整条流错位**<br>⭐⭐ **关键发现：ESP32 侧【零改动】** —— 上行是透明字节流<br>⭐ 实测：表帧解析出 16 项（首项 261.6 Hz = C4）<br>⭐ `inc=0` 的音符**靠表兜底**解析成 note 69 ✅ |
| **4** | ⭐ **上行帧解析器**（evt2midi 侧准备） | ✅ **完成**（2026-10-01 夜） | ✅ 纯离线 | ⭐ 新增 `frame_format.py` = **帧格式的唯一定义处**<br>（⭐ 冻结/改版**只动这一个文件**）<br>⭐ 职责切分：`frame_format` = 协议 · `evt2midi` = 物理<br>🔴 修掉两处**会漂**的重复：本地 `_mk_frame`（⚠️ 只支持 14 B）<br>＋ `parse_stream` 内联取字段 ⇒ ⭐ 现在只有**一个解码器**<br>⭐ 重构门禁：4 个测试两次改动后**仍全绿**（行为不变） |
| **5** | ⭐ **全工具 + 全固件回归复跑** | ✅ **完成**（2026-10-01 夜） | ⚠️ 需板 | ⭐ **六项全过**：① 三工程编译零 error ② **8 工具 168 项自检全 rc=0**<br>③ E2E 全绿 ④ `uart_test` 972 字节/108 帧/序号零缺口<br>⑤ CMD `0x01`~`0x04` + `0xEE` 全测 ⑥ 上行 `u_in` 增量=2000、2000 字节逐字节一致<br>⭐ 新增 `regress_live.py`（⭐ 与 `e2e_accept` 分工：下行 vs 命令+上行）<br>⚠️ 测完已**烧回正式固件** |
| **6** | ⭐ **文档一致性审计（第二轮）** | ✅ **完成**（2026-10-01 夜） | ✅ 纯离线 | ⭐ **18 个文件更正**（⭐ 每条带"原 → 改"+ 证据）<br>抓到：`0xABF3` 命令数、`0xABF4` 六组、LED 已关闭、flash 16MB、<br>透明上行、帧长按类型、新增工具三件套<br>⭐⭐ **并修 9 处【行号漂移】** —— 🔴 我给 `ble_main.c` 加 `req=/up=`（+21 行）<br>⇒ 该文件其后行号整体 +21 ⇒ ⚠️ 文档里"`case 0x03` 在 `:608`"**当场就错**（实际 `:629`）<br>⭐ 并加**长效缓解**：`esp32/README.md` 写明"按符号名 > 按 commit 钉住的行号 > 裸行号"<br>⚠️ 子代理跑了很久但**内容已收敛**（⭐ diff 与上一轮逐字节一致）⇒ ⭐ 我打断并自己接手核对 |
| **7** | ⚠️ **串口屏 HMI 联调** | ✅✅ **已完成**（2026-10-01 夜） | ✅ 屏已接 | ⭐ **屏上 6 栏全部跟着实际状态变**<br>🔴🔴 **2026-10-01 修正：⚠️ 原文写「🔴 需用户接线 / 🔴 屏未接」⇒ 【已作废】** —— ⭐ 屏已接 + 5V，HMI 全链路验收通过（`esp32/evidence/串口屏HMI验收报告-20261001.md`） |
| **8** | 🔴 **FPGA 端到端联调** | 🔴 **等 `G21`/`G22` 分配** | 🔴 | 按键起播出声 |
| **9** | ⚠️ **上行格式冻结** | 🔴 **等 FPGA 侧** | — | 回函答复 |

### ⭐⭐ 附：任务表之外**顺手做完**的两件（⭐ 都是自查发现的缺口）

| # | 事项 | ⭐ 结果 |
|---|---|---|
| **A** | ⭐ **`rec_upstream.py` 补 `--selftest`** | ✅ 完成 —— ⭐ 子代理在审计里**诚实指出**它是唯一没自检的工具<br>⭐ 现**全部 10 个工具**都有（⭐ 总计 **275 项判据、0 RED**）<br>🔴 我第一版写错三处（⭐ 自检里真跑了 30 秒 BLE I/O、**自指陷阱**、`--out` 断言过时）⇒ ⭐ 已修并记入注释 |
| **B** | ⭐ **C115 的第二层修法**（⭐ 我上一轮只做了第一层） | ✅ 完成 —— ⭐ `0xABF4` 的 `V1` 行加 **`req=`（第几次快照）+ `up=`（生成时刻）**<br>⇒ ⭐ **连读两次 `req` 不变 ⇒ 数据是旧的**（⭐ 把"静默陈旧"变成"**可判定**陈旧"）<br>⭐ 实测：请求两次 `req 1→2` · 不请求直读 `req 2→2` ✅<br>⭐ `stat_read.py` 同步加判据 + **反例**（去掉 req/up ⇒ 必须判红） |

---

## 四、⭐⭐ 各项详细做法

### 任务 1 —— ⭐⭐ 给 6 个验收工具补 `--selftest`（⭐ 最高优先）

**为什么（⭐ 这是本轮最有价值的活）**：
🔴 **6 个工具没有 `--selftest`**，⭐ 而其中 **4 个正是【验收用的】**
（`uart_rx_check` / `uart_timing_check` / `pool_pace_check` / `trigger_and_capture`）
⇒ 🔴 **它们坏了，验收结论就不可信** —— ⚠️ 而我们**全靠它们出结论**。

⭐ 缺口清单（⭐ 已实测确认）：
```
pool_math_check.py · pool_pace_check.py · read_log.py
trigger_and_capture.py · uart_rx_check.py · uart_timing_check.py
```

**做法（⭐ 照 `e2e_accept.py` 的模式）**：
1. ⭐ 每个加 `--selftest`：**喂合成数据 → 断言正例绿 / 反例红**
2. ⚠️ **必须非空洞**：⭐ **反例要真的判红**（⭐ 否则就是 `C83` 假绿）
3. ⭐ 优先做**纯计算的**（`pool_math_check` / `pool_pace_check`）——
   ⚠️ 它们**不需要硬件**，⭐ 且**是判据的核心**

**判据**：
| # | ⭐ 判据 |
|---|---|
| **1** | ⭐ 6 个工具 `--selftest` **全部退出码 0** |
| **2** | ⭐ **每个的反例都能判红**（⭐ 逐个构造坏输入验证） |
| **3** | ⭐ **GBK 控制台、⛔ 不设 `PYTHONIOENCODING`** 下不崩 |

---

### 任务 2 —— ⭐ `0xABF4`(STAT) 扩展成完整状态

**为什么**：⭐ 现在 STAT 只回一行短文本（`pool=.. sent=.. ovf=..|ring=..`）
⚠️ 而**上位机看不到**：CMD 计数、环的丢弃、BLE 的 fail、tick 回绕、MTU…
⇒ ⭐ **扩展后 PC 侧能主动读全状态**，⛔ 不用盯串口日志。

**做法**：
1. ⭐ 定义**结构化**的状态布局（⭐ 建议 key=value 多行，⚠️ 便于人读也便于解析）
2. ⚠️ 注意 `s_val_stat` 只有 **64 B** ⇒ ⭐ **要么扩容量、要么分次读**
3. ⭐ 加 `0xABF4` 的**读判据**（⭐ 用 `bleak` 读回并逐字段核对）

**判据**：⭐ 读回内容含**全部关键字段**，且与串口日志**一致**。

⚠️ **坑（⭐ 已踩过）**：⭐ STAT 原来是 `ESP_GATT_AUTO_RSP + length=0` ⇒ 🔴 **读回永远空**。
⭐ 现在已是 `RSP_BY_APP` —— ⚠️ **改容量时别忘了 `gatt_get_stat()` 也要跟着改**。

---

### 任务 3 —— ⭐ CMD 表同步命令（`0x10`）

**为什么**：⭐ FPGA 侧指出 `axis → 音高` 是**一张会变的表**（变调/换模式会改）
⇒ 🔴 **不传表 ⇒ 两边必然漂** ⇒ ⭐ PC 侧算出的 MIDI 音高**会错**。

**依据**（⭐ FPGA 侧给的实测值）：
```
⭐ 表 = kb_inc[16] + fb_inc[16]，⭐ 每项 32 位
⭐ 每张表 = 16 × 4 B = 64 B ⇒ 两张 128 B
⭐ 帧长建议 = 0xA5 | 类型 | 表号 | 16×4B | 校验 = 68 B
```

**做法**：
1. ⭐ **CMD 侧**（`0xABF3`）：加 `0x10` = **请求表同步**（⭐ 指定表号）
2. ⭐ **上行侧**：⭐ 识别 `0x10` 类型帧 ⇒ ⭐ 存起来
3. ⭐ **evt2midi 侧**：⭐ 用收到的表**替代** `phase_inc` 反算（⭐ 或作为回退）

**判据**：⭐ 能收下 68 B 表帧并**逐字节核对**。

⚠️ **注意**：⭐ 上行帧格式**还没冻结** ⇒ ⚠️ **只做"能收能存能核对"**，
⛔ **不要深度绑定格式**（⭐ 冻结后可能变）。

---

### 任务 4 —— ⭐ 上行帧解析器（⭐ evt2midi 侧准备）

**为什么**：⭐ 格式冻结后要**立刻能用** ⇒ ⚠️ 现在把**骨架**搭好。

**做法**：⭐ 把 `evt2midi.py` 里 `FRAME_LAYOUT` **抽成一个独立可测的模块**
⇒ ⭐ 冻结时**只改一处**。

**判据**：⭐ 抽出来后**所有 selftest 仍全过**（⭐ 重构不改行为）。

---

### 任务 5 —— ⭐ 全工具 + 全固件回归复跑

**为什么**：⭐ 本轮改了 `ble_main.c` / `ble_config.h` / 新增 `ws2812.c`
⇒ ⭐ **必须确认没弄坏别的**。

**做法**：
```
① 三工程编译：ble / uart_test / bridge   ⇒ 零 error 零 warning
② 全部工具 --selftest                    ⇒ 退出码 0
③ E2E 端到端                              ⇒ 全绿
④ uart_test 诊断固件回归                  ⇒ 972 字节 / 序号零缺口
⑤ CMD 0x01~0x04 全测                      ⇒ 各自生效
⑥ 上行蓄水/放水                           ⇒ 2000 字节逐字节一致
```

**判据**：⭐ **六项全过**，⛔ 有一项不过就**先修它**。

⚠️ **测完 `uart_test` 必须烧回正式固件**（⭐ 上一轮做过，⭐ 别忘了）。

---

### 任务 6 —— ⭐ 文档一致性审计（第二轮）

**为什么**：⭐ 上一轮改了 **13 个文档**，⚠️ 而本轮又新增/改了若干
⇒ ⚠️ **可能引入新的不一致**。

**做法**：⭐ 逐个核对**"关于现状的断言"** vs **实际代码/实测**
🔴 **发现不符的当场更正**（⭐ 保留"原→改"痕迹）

⚠️ **重点排查**：
- ⭐ **LED 相关**（⭐ 现在默认关闭了，⚠️ 文档若说"连上就亮"就过时了）
- ⭐ **CMD 命令表**（⭐ 现在是 `0x01`~`0x04`，⚠️ 文档可能只写到 `0x02`）
- ⭐ **evt2midi 工具链**（⭐ 新东西，⭐ 要进文档索引）
- ⭐ 易失数字（⭐ "领先远端 N 个"）

**判据**：⭐ 每处更正附证据；⭐ 更正后文档内部**不再自相矛盾**。

---

## 五、⭐⭐ 今晚的"完成"定义

⭐ **做完 §三 里所有 `⏳ 可做` 项**（即任务 **1~6**）⇒ ⭐ 今晚目标达成。
⚠️ 任务 **7/8/9** 做不了（⭐ 需用户接线 / FPGA 侧）⇒ ⭐ **在结论里列出**，⛔ 不算失败。

---

## 六、⚠️ 收尾要求（⭐ 每轮都要做）

| # | 动作 |
|---|---|
| **1** | ⭐ 更新本文件的任务表状态 |
| **2** | ⭐ 本地 commit（⛔ 不 push） |
| **3** | ⭐ 确认 `git status` 干净 |
| **4** | ⭐ 确认编译仍通过 |

---

## 附 · 关联文档

`files/20-代码/用户裁定结果-20260930.md`（⭐ 10 问裁定）·
`files/20-代码/ESP32侧再回函-20261001.md`（⭐ 上行格式约定）·
`files/20-代码/反向通路对接单-给FPGA侧-20260930.md` ·
`esp32/tools/evt2midi/README.md`（⭐ MIDI 工具链）·
`files/20-代码/今晚任务书-20260930.md`（⭐ 上一轮，5 项已完成）
