hokuu1102/Gowin2026-PolySynth/files/20-代码/文档一致性审计-20261001-第三轮.md

# 🔍 文档 ↔ 代码 一致性审计（⭐ 第三轮 · 2026-10-01）

> **审计人**：ESP32 线子代理（⭐ 本轮**只写** `files/20-代码/**`）
> **审计对象**：`files/20-代码/**` 的 **72 个 `.md`**
> **核对基准（⭐ 只读）**：`esp32/**`（⭐ 真实代码）· `rtl/top.v` / `constr/top.cst`（⭐ **只用 `FPGA2026` main worktree 的权威副本**，⛔ 本 worktree 的是旧快照）
> **动机**：⚠️ 上一轮在**代码**里做了事，**文档没跟上** ⇒ 出现「文档说没做、代码其实做了」这类**会误导下一个接手人**的陈述。
> **纪律**：⛔ **未做任何 git 写操作**；⛔ **未改** `esp32/**`、`rtl/**`、`constr/**`、`tb/**`、`sim/**`、`bringup/**`。
> **改动范围**：⭐ **23 个既有 `.md`** + ⭐ **本报告**（⛔ 无其它新增）。

---

## 一、⭐ 审计范围

### 1.1 全量清点

`files/20-代码/` 下共 **72 个 `.md`**（⭐ `Get-ChildItem -Filter *.md` 枚举，⛔ 无遗漏）。

### 1.2 逐条核验并**已修改**的 23 个文件

| # | 文件 | 改后行数 | 改动量（+/-） |
|---|---|---|---|
| 1 | `ESP32线交接文档-20261001.md` | 395 | **+35 / −10** |
| 2 | `反向通路对接单-给FPGA侧-20260930.md` | 466 | +21 / −1 |
| 3 | `标定链接入top实施方案-20260923.md` | 347 | +17 / −7 |
| 4 | `ESP32侧工作计划-20260930.md` | 187 | +13 / −9 |
| 5 | `ESP32侧接续准备-20260923.md` | 261 | +12 / −0 |
| 6 | `ESP32通路总体架构-20260922.md` | 409 | +11 / −2 |
| 7 | `上位机与ESP32通路实施计划.md` | 552 | +11 / −0 |
| 8 | `上行通路缓冲设计-20260930.md` | 762 | +9 / −1 |
| 9 | `矛盾裁定单-方案3与模式B-20260930.md` | 341 | +9 / −2 |
| 10 | `ESP32侧详细执行计划-20260930.md` | 277 | +8 / −2 |
| 11 | `TX回传增强设计-20260924.md` | 265 | +8 / −2 |
| 12 | `今晚任务书-20260930.md` | 282 | +8 / −8 |
| 13 | `蓝牙需求分析与实施规划.md` | 502 | +8 / −5 |
| 14 | `今晚任务书-20261001.md` | 250 | +7 / −5 |
| 15 | `事件格式改动牵扯面-20260924.md` | 134 | +6 / −2 |
| 16 | `待用户裁定问题清单-20260930.md` | 187 | +6 / −6 |
| 17 | `ESP32侧再回函-20261001.md` | 194 | +3 / −3 |
| 18 | `ESP32上机实测问题分析-20260924.md` | 340 | +2 / −2 |
| 19 | `用户裁定结果-20260930.md` | 159 | +2 / −2 |
| 20 | `ESP32线当前断点-20260924.md` | 146 | +1 / −1 |
| 21 | `ESP32通路交接文档-20260922.md` | 702 | +1 / −1 |
| 22 | `曲谱通路接入设计-20260924.md` | 361 | +1 / −1 |
| 23 | `降档请求单-1M到500k-20260930.md` | 372 | +1 / −1 |

> ⭐ **改动纪律**：⭐ 全部**定点替换**（⛔ 无整篇重写）⇒ `git diff --numstat` 增删数都很小，⭐ **行尾 LF 未被改成 CRLF**。
> ⭐ 全部 **UTF-8 无 BOM**（⭐ 逐个回读首字节确认，⛔ 不是 `EF BB BF`）。

### 1.3 只读核验、判定为一致、⛔ 未改的

`降档请求单`（⭐ 部分）· `ESP32侧回应-FPGA答复-20260930.md` · `ESP32侧串口命令格式-给FPGA侧-20260923.md`（⭐ 已有 2026-09-30 更正块）· `已知问题与风险清单.md`（⭐ 关键词扫描）等。

---

## 二、⭐⭐ 发现清单

> **分级**：🔴🔴 = **会把"从未验证"说成"已验证"**（⭐ 最危险）／🔴 = 会误导接手人（⭐ 已修）／⚠️ = 无害但过期（⭐ 已修）／✅ = 已核实一致（⭐ 未改）。

---

### 2.A 🔴🔴 最高级 —— ⭐ 交接文档把**「从未端到端验证」写成了「✅ 已通」**

**文档原文**（`ESP32线交接文档-20261001.md` §一「⭐ 当前**已通**的东西」，改前 `:37-38`）：

| 行 | 原文 | 原文状态 |
|---|---|---|
| 1 | `\| ⭐ **ESP32 → UART1 → FPGA** \| ⭐ 972 B / 108 帧，⭐ 序号 `0..107` 完整 \| ✅ \|` | ✅ |
| 2 | `\| ⭐ **FPGA → UART1 → ESP32 → BLE → PC** \| ⭐ 2000 B **逐字节相同** \| ✅ \|` | ✅ |

**🔴 实际测的是什么**：⭐ 第 1 行对端是 **CH340 USB-TTL**；⭐ 第 2 行是**跳线/上位机桩注入 `GPIO18`**。

**依据（⭐ 五条，⭐ 全部是报告**自述**的范围，⛔ 不是我的推断）**：

1. ⭐ `esp32/evidence/UART验收报告-20260930.md:3`：`> **目的**：⭐ **证明「ESP32 从 `GPIO17` 发出的字节是正确的」**（⚠️ 不上 FPGA）`
2. ⭐ `esp32/evidence/反向通路验收-ESP32侧-20260930.md:5`：`> **范围**：⚠️ **只证明 ESP32 侧** —— 🔴 **不证明 FPGA 能发**`
3. ⭐ `files/20-代码/降档请求单-1M到500k-20260930.md:218`（⭐ 已实测核实）：`CH340 @1 Mbps ｜ 972 字节，序号 0..107 零缺口 ｜ 🔴 那是 **USB-TTL + 短线**，⛔ **不是 FPGA 链路**`
4. ⭐ 操作步骤**文件名**就叫 `esp32/UART验证-不上FPGA.md`；⭐ `esp32/README.md:176`：`PC ──USB-TTL──> ESP32 的 UART1 RX ← ⚠️ **不接 FPGA 时，用 USB-TTL 当"假 FPGA"**`
5. ⭐ `files/20-代码/ESP32侧再回函-20261001.md:15`（⭐ **同一时期**）：`🔴 `PMOD0`（含 `G21`/`G22`）未分配 ⇒ **ESP32 ↔ FPGA 一根线都没有**`

**🔴 结论**：⭐ **ESP32 ↔ FPGA 这条链路【从未端到端验证过，一次都没有】。**

**⚠️ 为什么这条最危险**：⭐ 它写在「**已通**」表里并打 `✅` ⇒
🔴 **下一个接手人会以为"只剩接根线"**，⭐ 而实际是**整条链路（波特率/引脚/电平/帧边界/反向时序）一次都没在真硬件上跑过**。

**处置**：✅ **已改** —— ① 两行降级为「⚠️ **仅 ESP32 侧**（对端 CH340 / 桩，⛔ 非 FPGA）」；
② §一 表下**新增口径块**（⭐ 引上面五条原文）；③ §八 P1 判据改为「**首次端到端：`ESP32 → G22 → FPGA 收` ＋ `FPGA → G21 → ESP32`**，⭐ **判据必须落在真 FPGA 上**」。

---

### 2.B 🔴 功能状态类 —— ⭐「文档说没做，代码其实做了」

| # | 文件:行（⭐ 改前） | 文档原文 | 🔴 依据 `file:line` + 实际值 | ✅ |
|---|---|---|---|---|
| B1 | `今晚任务书-20261001.md:84` | `\| **3** \| ⭐ **CMD 表同步命令**（`0x10`） \| ✅ **完成** … \|` | ⭐ `ble_main.c` 的 `case` **只有** `0x01`(`:659`)/`0x02`(`:673`)/`0x03`(`:691`)/`0x04`(`:696`)/`0x20`(`:712`)/`0x21`(`:724`)/`0x22`(`:753`) ⇒ 🔴 **没有 `case 0x10`**；⭐ 全 `esp32/**/*.{c,h}` 搜 `case 0x10\|TABLESYNC\|表同步` = **0 命中** | ✅ 已改（⭐ 标题改「表同步帧解析（⚠️ **不是** CMD `0x10`）」，状态改「⚠️ 部分完成」，⭐ 写明待办仍在） |
| B2 | `ESP32通路总体架构-20260922.md:358` | `…⇒ ⭐ **需新增起播命令**（⚠️ 待实现）` | ⭐ `ble_main.c:691` `case 0x03:`（起播）· `:696` `case 0x04:`（停止） | ✅ 已改 |
| B3 | `今晚任务书-20260930.md:79` | `\| **8** \| 🔴 **FPGA 端到端联调** \| 🔴 **需硬件** \| 🔴 需 `uart_tx.v` \|` | ⭐ `FPGA2026/rtl/top.v:943` `uart_tx #(` · `:945` `.BAUD_DIV(100)` · `:928` `uart_tx_fifo #(.DEPTH(8))` | ✅ 已改 |
| B4 | `待用户裁定问题清单-20260930.md:19` | `\| **Q6** \| ⚠️ **`uart_tx.v` 做不做？** … 🔴 **不做 ⇒ 反向通路永远收不到东西** \|` | ⭐ 同 B3 | ✅ 已改 |
| B5 | `今晚任务书-20260930.md:80` | `\| **9** \| ⚠️ **起播架构裁定** \| 🔴 **等用户/FPGA 侧** \|` | ⭐ `files/20-代码/用户裁定结果-20260930.md` 已裁定 Q1 = 模式 B；⭐ 代码 `:691`/`:696` 已落地 | ✅ 已改 |
| B6 | `蓝牙需求分析与实施规划.md:6/158/159/160/162` | `状态：🟡 **规划，⛔ 未开工**` · `play_seq.v 🔴 未创建` · `UART 接进 top.v 🔴 未做` · `ESP32 固件 🔴 未开工` · `结论：⚠️ **这条链【缺 3 环】**` | ⭐ `rtl/w3c/play_seq.v` 存在；⭐ `FPGA2026/rtl/top.v:697`/`:829`/`:943` 已例化；⭐ `esp32/ble/**` 已落地验收 | ✅ 已改（⭐ 文件头 banner + 三行 + 结论块） |
| B7 | `上位机与ESP32通路实施计划.md:20` | `🟡 `rtl/w3c/uart_rx.v` ✅ 已验证，⚠️ **但没接进 `top.v`**` | ⭐ 同 B6 | ✅ 已改（⭐ 新增文件头 banner） |
| B8 | `上行通路缓冲设计-20260930.md:55/59` | ``#define BLE_UART_RX_BUF (FRAME_BYTES * 114) /* 1026 B */`` · `⇒ ⭐ **驱动 RX 环形缓冲 = 1026 字节。**` | ⭐ `ble_config.h:143` `#define BLE_UART_RX_BUF (8 * 1024) /* 8192 B */`；⭐ `ble_main.c:194` `uart_driver_install(BLE_UART_PORT, BLE_UART_RX_BUF, …)` | ✅ 已改（⭐ 并点明与 §五「用户选择了环，⛔ 不是调大驱动缓冲」的冲突） |
| B9 | `待用户裁定问题清单-20260930.md:21` | `\| **Q8** \| ⭐ **接通 2MB → 16MB 映像头，认不认？** \| 🔵 低 \| ⚠️ 浪费 14 MB flash \|` | ⭐ `esp32/ble/sdkconfig.defaults:40-41` `CONFIG_ESPTOOLPY_FLASHSIZE_16MB=y` / `"16MB"` | ✅ 已改 |
| B10 | `ESP32通路总体架构-20260922.md:305` | `\| **4** \| 波特率最终值… \| ⭐ **1 Mbps**（`BAUD_DIV 434→50`）… \| ✅ 与我固件默认值一致 \|` | ⭐ `ble_config.h:84` `BLE_BAUD 500000` · `uart_test_main.c:52` `TEST_BAUD 500000` · `bridge_config.h:59` `BRIDGE_BAUD 500000` · `FPGA2026/rtl/top.v:702` `.BAUD_DIV(100)` | ✅ 已改 |

---

### 2.C 🔴 「串口屏未接 / HMI 从未真机跑过」—— ⭐ **9 处**

**文档原文**：

| 文件:行（⭐ 改前） | 原文 |
|---|---|
| `ESP32侧工作计划-20260930.md:37` | `⚠️ **仍未做**：`uart_test` 诊断固件回归（⚠️ 需板）· 串口屏联调（🔴 屏未接）。` |
| `ESP32侧工作计划-20260930.md:127` | `\| **J** \| … \| ⚠️ ⭐ HMI 从未真机验证 ⇒ ⚠️ 可能已脱节 \|` |
| `ESP32侧工作计划-20260930.md:136` | `\| ⚠️ 屏至今未接 ⇒ ⭐ **HMI 397 行代码从未跑过** \|` |
| `待用户裁定问题清单-20260930.md:22` | `\| **Q9** \| … \| ⚠️ HMI 397 行代码**从未真机跑过** \|` |
| `待用户裁定问题清单-20260930.md:146` | `⚠️ **现状**：🔴 **屏至今未接** ⇒ ⭐ **HMI 397 行代码从未在真机跑过**。` |
| `今晚任务书-20260930.md:78` | `\| **7** \| ⚠️ **串口屏 HMI 联调** \| 🔴 **需硬件** \| 🔴 屏未接 \|` |
| `今晚任务书-20261001.md:88` | `\| **7** \| ⚠️ **串口屏 HMI 联调** \| 🔴 **需用户接线** \| 🔴 屏未接 \|` |
| `ESP32侧详细执行计划-20260930.md:22` | `\| **5** 等你接线 \| 「🔴 需硬件」 \| ⏳ **仍待做**（🔴 屏未接） \|` |
| `ESP32上机实测问题分析-20260924.md:313` | `\| 3 \| ⚠️ **串口屏未接**（`hmi: no 0x88 ACK` 是"没接屏"的正常降级） \|` |

**依据（⭐ 逐字节核过，⛔ 不是"另一份文档也这么说"）**：

- ⭐ `esp32/evidence/串口屏HMI验收报告-20261001.md:6`：`**状态**：✅✅ **通过** —— ⭐ **屏上五栏全部跟着实际状态变化**`
- ⭐ 同文件 `:12-19` 逐条判据：`g0` ✅ · `t2` = `200/200` ✅ · `j0`/`n0` = `100%` ✅ · `t1` ✅ · `t3` = `BT OK` 绿 / `BT --` 红 ✅ · `hmi.rx` 涨（含 `0x65`）✅
- ⭐ 同文件 `:5` 记录实际接线：`GPIO4`(TX)→屏 `RX` · `GPIO5`(RX)←屏 `TX` · **5V** · `GND`
- ⭐ `ble_config.h:451-452` = `BLE_PIN_HMI_TX 4` / `BLE_PIN_HMI_RX 5` ✅ 与接线记录一致
- ⭐ `ble_main.c:753` = `case 0x22: {`（⭐ 曲名命令）

**处置**：✅ **9 处全部已改**（⭐ 每条保留"原文写 X ⇒ 已作废 ⇒ 实测 Y + 证据路径"）。

---

### 2.D 🔴 幽灵行号 / 行号漂移

#### D1 —— ⭐⭐ `pool.c:412(-413)` 是**幽灵行号**（⭐ 同一条错写在 **5 个文件**里）

| 文件:行（⭐ 改前） | 原文 |
|---|---|
| `ESP32侧再回函-20261001.md:106` | `…锚在**自己的 `esp_timer`** 上（`pool.c:412`）。` |
| `ESP32侧再回函-20261001.md:192` | `\| ⭐ ESP32 起播锚点 \| ⭐ 我们侧 `pool.c:412-413` \|` |
| `用户裁定结果-20260930.md:38` | `…锚在**自己的 `esp_timer`** 上（`pool.c:412-413`）` |
| `待用户裁定问题清单-20260930.md:39` | `**ESP32 的 `esp_timer`** 上（`pool.c:412-413`）⇒` |
| `矛盾裁定单-方案3与模式B-20260930.md:33` | `…锚在**自己的 `esp_timer`** 上（`pool.c:412`）；` |

**依据（⭐ 这正是 `C100` 说的"最强自报警信号"）**：

- ⭐ `esp32/ble/main/pool.c:412` = `(unsigned)(nframes - take_frames),` —— 🔴 **是 `pool_push()` 里 `ESP_LOGE("POOL FULL")` 的一个参数行**
- ⭐ 实测**真正的锚点**在 `esp32/ble/main/pool.c:461-462`：
  ```c
  461:  s_t0_tick  = (uint32_t)ev_tick(pool_peek_word(0));
  462:  s_t0_us    = esp_timer_get_time();
  ```
  （⭐ 所在函数 `void pool_start(void)` @ `:457`）

**处置**：✅ **五处全部已改**。⚠️ ⭐ 同一错行号还在 `esp32/ble/main/ble_config.h:372`（⭐ 属 `esp32/`，⛔ 不是我的范围 ⇒ 见 §七 U5）。

#### D2 —— ⭐ `反向通路对接单` 附录**全部 12 个行号漂移**

**文档原文**（`反向通路对接单-给FPGA侧-20260930.md:410-418`，改前）：
`ble_main.c:607-685` · `:650-663` · `:646` · `:642-644` · `:664-667` · `:626-640` · `:682` · `:736-745` · `:103-105/261/321/353` · `ble_config.h:200` · `:330-331` · `:164`

**依据（⭐ 逐条实测，⛔ 无一条对得上）**：

| ⭐ 符号 | 🔴 原文 | ✅ 实测 |
|---|---|---|
| `task_uart_to_ble()` | `:607-685` | **`:1100`** |
| `uart_read_bytes()`（唯一 UART1 读者） | `:613` | **`:1106`** |
| `s_mtu - 3`（分块上限） | `:646` | **`:1163`** |
| `s_connected && s_handle_noti` | `:642-644` | **`:1160`** |
| `BLE_DELAY_TICKS_AT_LEAST_1(BLE_TX_GAP_MS)` | `:682` | **`:1213`** |
| `task_drain()` / `task_status()` | `:690-751` | **`:989`** / **`:1228`** |
| `s_uart_rx_bytes` 定义 | `:68-77` | **`:82`** |
| `pool_set_expected()` 调用点 | `:464` | **`:909`** |
| `BLE_TX_GAP_MS` | `ble_config.h:200` | **`ble_config.h:226`** |
| `BLE_DELAY_TICKS_AT_LEAST_1` | `ble_config.h:330-331` | **`ble_config.h:356-357`** |
| `BLE_PREFERRED_MTU=517` | `ble_config.h:164` | **`ble_config.h:190`** |
| `BLE_UART_RX_BUF` | `ble_config.h:117`（1026 B） | **`ble_config.h:143`（8192 B）** |

⭐ **根因**：`ble_main.c` 其后因新增 `req=`/`up=` 与 CMD `0x20`/`0x21`/`0x22` **整体下移**（⭐ `今晚任务书-20261001.md:87` 已记录同类事故）。

**处置**：✅ **已改** —— ⭐ 附录前插**完整映射表** + "⛔ 不要按行号跳转，⭐ 一律按符号名定位"（⛔ 未逐条改写 30 处）。

#### D3 —— ⭐ 「六组 / 261 B > `char buf[256]` ⇒ 可能截断」在 **6 处**（⭐ 实际 8 行 / 320 B）

| 文件:行（⭐ 改前） | 原文 | 🔴 实测 |
|---|---|---|
| `ESP32侧工作计划-20260930.md:31` | `⭐ 现值 = **六组**（…`ble_main.c:336`）… 🔴 **尺寸警告**：⭐ 样本 **261 B** > `char buf[256]`（`:352`）⇒ ⚠️ **可能截断尾部**` | ⭐ `ble_main.c:419-435` = **8 行**；⭐ `:389` = `char buf[320];`；⭐ `:362` = `static void cmd_report_status(void)` |
| `ESP32侧工作计划-20260930.md:122` | `…**六组**（`ble_main.c:336` `cmd_report_status()`；缓冲区 256 B，`gatt_svc.c:99`）… **261 B** > `char buf[256]`（`:352`）…` | ⭐ `gatt_svc.c:106` = `static uint8_t s_val_stat[320];` |
| `ESP32侧再回函-20261001.md:149` | `…⭐ 现已**扩成六组**（…`ble_main.c:336`，缓冲区 256 B 见 `gatt_svc.c:99`）…` | ⭐ 同上 |
| `今晚任务书-20260930.md:214` | `⭐ **现为六组 / 约 221 字节**，…（…`ble_main.c:613`）\| `esp32/ble/main/ble_main.c:336` …` | ⭐ `CMD 0x02` 调用点 @ `:675` |
| `今晚任务书-20260930.md:235` | `\| ⭐ **六组 / 约 221 字节**；…（… ⚠️ **无过期标记**）\| `ble_main.c:336` · `:592`；`gatt_svc.c:99` \|` | ⭐ 格式串 **8 行**（⭐ `:419-435`）；🔴 **「无过期标记」也错** —— `:403-404`/`:443` 表明 `V1` 行已带 `req=`/`up=` ⇒ ⭐ **陈旧【可判定】** |
| `ESP32侧详细执行计划-20260930.md:21` | `🔴 另：`0xABF4` **已扩成六组**（+ ⭐ `V1` 行带 `req=`/`up=` …，提交 `35036bf`），…（…`:613`）` | ⭐ 同上 |
| `ESP32通路交接文档-20260922.md:16`（⭐ **2026-10-01 的更正 banner 自身**） | `\| **4** \| ⭐ **`0xABF3` 四个命令**（`0x01`/`0x02`/`0x03`/`0x04`）· ⭐ **`0xABF4` 六组 / 约 221 字节，且是【拉取快照】** \|` | ⭐ CMD 实为 **7 个**（⭐ `:659`/`673`/`691`/`696`/`712`/`724`/`753`）；⭐ STAT 实为 **8 行** |

**⚠️ 顺带：一个"派生常量"混乱**（⭐ `C88` 同族）—— ⭐ 同一字节数在工程里有 **四个互相矛盾的值**：
`gatt_svc.c:91`「约 **210**」· `今晚任务书-20260930.md`「约 **221**」· `工作计划`「**261**」· `交接文档-20261001`「**264**」。
⇒ ⭐ 我在文档与报告里**⛔ 不再断言某个字节数**，⭐ 改指**权威判据 = `stat_read.py` 的"组齐全"检查**。

**处置**：✅ **6 处全部已改**（⭐ 含行号 `:336`→`:362`、`:352`→`:389`、`gatt_svc.c:99`→`:106`、`:613`→`:675`）。

---

### 2.E 🔴 仓库 ↔ worktree 关系被写错（⭐ 措辞类，⭐ **7 处**）

> ⭐ **权威出处（⭐ 本项目里"worktree"这件事【已经写对过】）**：`esp32/README.md:81-89`。
> ⚠️ 本节全部**对齐该处表述**并**互指**，⛔ 不另造一套。

**⭐ 实测事实（⭐ 我自己复核过）**：

| ⭐ 判据 | ⭐ 实测值 |
|---|---|
| 本目录 `.git` | ⭐ **是一个【文件】**（`Attributes = Hidden, Archive`，⛔ 无 `Directory`），内容 = `gitdir: C:/Users/hokuu/Desktop/FPGA/FPGA2026/.git/worktrees/FPGA2026-esp32` |
| `git rev-parse --git-dir` | `…/FPGA2026/.git/worktrees/FPGA2026-esp32` |
| `git rev-parse --git-common-dir` | 🔴 `…/FPGA2026/.git` ⇒ ⭐ **与 `FPGA2026` 同一个** |
| `git worktree list` | ⭐ **22 个 worktree 共用这一个 `.git`** |
| `git tag -l "pre-squash/*"` | ⭐ **36 个**（⭐ 含 `pre-squash/2026-10-01`） |
| `git tag --points-at HEAD` | 🔴 **（空）** |

⇒ ⭐ **真实关系 = 「同一个 git 仓库的两个 `git worktree`」**，⛔ **不是两个独立仓库**。

**⚠️ 后果（⭐ 这才是要写进文档的）**：

1. 🔴 **分支 / tag / 远端跟踪 ref 是【共享命名空间】** ⇒ ⛔ **不能假设"我在 A 里打 tag / 改分支不影响 B"**。
2. ✅ **`HEAD` / 索引 / 工作区是【各自】的** ⇒ ⚠️ **正因为"切分支互不干扰"，更容易误以为整体隔离**。
3. 🔴 **实测踩到的坑**：⭐ `pre-squash/2026-10-01` **已被另一条线占用**（⭐ 实测该 tag 存在），
   ⚠️ 而备份脚本的守卫是"存在就跳过" ⇒ **HEAD 其实没被任何 tag 钉住，脚本却打印"已存在，跳过"继续往下走**。
   ✅ **正确判据：`git tag --points-at HEAD` 非空**（⛔ 不是"`git tag` 命令没报错"）。⭐ 实测**当前为空**。

**文档原文（⭐ 7 处）**：

| # | 文件:行（⭐ 改前） | 🔴 原文 | ✅ 处置 |
|---|---|---|---|
| E1 | `ESP32线交接文档-20261001.md:5` | `> **仓库**：`…FPGA2026-esp32`（⭐ **⛔ 不是 `FPGA2026`**，⭐ 两个同时开着，⭐ 这是头号混淆源）` | ✅ 已改（⭐ 改成"同一仓库的两个 worktree，共用 `.git`；ref 共享、HEAD/索引各自" + 三条实测 + 互指 `esp32/README.md:81-89`） |
| E2 | `ESP32线交接文档-20261001.md:302`（交接 prompt） | `· 仓库：…（⛔ 不是 FPGA2026，两个同时开着）` | ✅ 已改（⭐ 同上，⭐ 精简版） |
| E3 | `矛盾裁定单-方案3与模式B-20260930.md:238` | `### 2.2 🔴 根因：⭐ **两个仓库不同步**（…）` | ✅ 已改（⭐ 标题改「同一个仓库的两个 `worktree` 不同步」+ 说明真差异在**分支/提交位置**） |
| E4 | `降档请求单-1M到500k-20260930.md:19` | `…⚠️ **正是交接文档第八条警告的"两个仓库"坑。**` | ✅ 已改 |
| E5 | `ESP32线当前断点-20260924.md:39` | `> ① 合并发生在**另一个仓库**（⚠️ 注意：本 worktree 与主工作区**共用同一个 `.git`**）` | ✅ 已改（⭐ 括号里本来就对，⭐ 主句错 ⇒ 改「另一个分支 / worktree」） |
| E6 | `曲谱通路接入设计-20260924.md:360` | `\| ⭐ ESP32 侧协议（⚠️ 另一仓库） \| …` | ✅ 已改 |
| E7 | `标定链接入top实施方案-20260923.md:334` | `\| ⭐ ESP32 侧协议（⚠️ 另一仓库） \| …` | ✅ 已改 |
| E8 | `事件格式改动牵扯面-20260924.md:125/127` | `# ⚠️ 注意要【两个仓库都扫】` / `# ⭐ ESP32 worktree 也要扫（⭐ 另一个目录）` | ✅ 已改（⭐ 改成"两个 worktree 都扫"） |

**⭐ 顺手补的纪律（⭐ 你指的第 2 项）**：

| 文件:行 | 🔴 问题 | ✅ 处置 |
|---|---|---|
| `ESP32侧详细执行计划-20260930.md:145` | `git tag pre-squash/2026-09-30d  # ⭐ 备份 tag(⚠️ c 已用)` —— ⛔ **只有"c 已用"这种人工记忆，没有机械判据** | ✅ 已在流程里**插入 `git tag --points-at HEAD`** + 4 行理由注释 |
| `ESP32侧详细执行计划-20260930.md` §3.3 判据表 | ⛔ 缺"HEAD 真被钉住"这条判据 | ✅ **新增判据 3b**：`git tag --points-at HEAD` **非空** |
| `ESP32线交接文档-20261001.md:200`（纪律表第 3 条） | `先 tag pre-squash/<日期> + git bundle 到仓库外` —— ⛔ 无核对步骤 | ✅ 已补（⭐ 含"ref 共享 ⇒ 名字可能被占用 ⇒ 静默跳过"的理由） |
| `ESP32线交接文档-20261001.md:239`（push 流程） | 同上 | ✅ 已改（⭐ 指向纪律表） |
| `ESP32线交接文档-20261001.md:319`（交接 prompt） | 同上 | ✅ 已补 |

---

### 2.F 🔴 `constr/` 副本同样过期 —— ⭐ 且**会让人得出完全相反的结论**

**⭐ 实测（⭐ 可复核）**：

| 文件 | 本 worktree `FPGA2026-esp32\` | 权威 `FPGA2026\` | 结论 |
|---|---|---|---|
| `constr/top.cst` | 17989 B · SHA256 `92DC1281…` | **29480 B · SHA256 `1C22CF12…`** | 🔴 **不是同一版本** |

**🔴 过期副本会让人得出【完全相反】的结论**：

| ⭐ 项 | 🔴 本 worktree 副本 | ✅ 权威副本 |
|---|---|---|
| `uart_rx` | `:253` `IO_LOC  "uart_rx" V14;`（⭐ BANK8 · 板载 BL616） | `:364` `IO_LOC  "uart_rx" D14;`（⭐ **J9 · N26 · SDRAM0_A6 · BANK1**） |
| `uart_tx` | `:255` `IO_LOC  "uart_tx" U15;`（⭐ BANK6 · 板载 BL616） | `:366` `IO_LOC  "uart_tx" D15;`（⭐ **J9 · N25 · SDRAM0_A5 · BANK1**） |
| 接线说明 | ⛔ 无 | `:352-353`「⭐ USB-TTL 的 TX → J9 的 N26 · ⭐ USB-TTL 的 RX → J9 的 N25」· `:357`「⚠️ **代价**：⭐ **板载 `BL616` 的那路 UART 从此不接**」 |
| 搬迁记录 | ⛔ 无 | `:331`「🔴🔴 **2026-09-24 晚：UART 从板载搬到了 `J9` 排针**（⭐ 用户拍板）」 |
| `PMOD0`（含 `G21`/`G22`） | — | `:137`「· `PMOD0`（`V18 V19 G21 G22 F18 E18 C22 B22`）⇒ **当前未分配**。」⇒ ⭐ **P1 的阻塞是真的**（⛔ 不是过时结论） |

**📌 已在 `files/20-代码/**` 里按此修正的 2 处**（⭐ 其余 `constr/` 引用核对后**判定一致或与引脚无关**）：

| 文件:行（⭐ 改前） | 🔴 原文 | ✅ 处置 |
|---|---|---|
| `标定链接入top实施方案-20260923.md:199-200` | `\| `uart_rx` \| **input** \| ⭐ **`V14`** \| …` · `\| `uart_tx` \| **output** \| ⭐ **`U15`** \| …`（⭐ 并给出 `IO_LOC "uart_rx" V14;` 那 4 行） | ✅ 已改（⭐ ball 改 `D14`/`D15` + BANK1；⭐ 旧 4 行标"已作废"；⭐ 附 5 条权威副本出处 + SHA 对比） |
| `TX回传增强设计-20260924.md:214-215` | `⇒ ⭐ 而项目已用的 `uart_rx`（`V14`）**也是 `BANK8`**（⭐ `constr/top.cst:250` 注释实测）⇒ ⭐ **同一个 BANK ⇒ 同一个电平 ⇒ `LVCMOS33`** ✅` | ✅ 已改（⭐ 该**交叉验证链已断** —— `uart_rx` 现属 **BANK1**；⭐ 但**本节结论仍独立成立**，⭐ 依据是 `files/10-硬件/开发板与引脚资料.md:159`） |

**✅ 核对为一致、⛔ 未改的一处**：`ESP32侧回应-FPGA答复-20260930.md:30` 引 `constr/top.cst:137`「`PMOD0`（含 `G21`/`G22`）⇒ 【当前未分配】」⇒ ⭐ **与权威副本 `:137` 逐字一致** ✅（⭐ 属 §四 C8）。

**🔴 📌 建议（⭐ 由主会话执行，⛔ 不在我的写入范围）**：
⭐ **把 `esp32/README.md:81-89` 那条警告的覆盖面从 `rtl/` 扩到 `constr/`**（⭐ 以及任何"FPGA 线维护、本 worktree 有副本"的目录），
⭐ 并给出**机械判据**：⛔ 别靠"我记得它旧" ⇒ ✅ **比 SHA256 / 比文件大小**，⭐ 或直接读权威路径 `C:\Users\hokuu\Desktop\FPGA\FPGA2026\`。

**⚠️ 顺带记一条（⭐ 权威副本【自己内部】的过时注释，⭐ 属 FPGA 线文件，⛔ 不改，⭐ 只记录）**：
⭐ 权威 `constr/top.cst:327` 写 `//         `rtl/w3c/uart_tx.v` 存在（162 行）· `top.v` 里已例化（`u_uart_tx`，**`BAUD_DIV=50`**）`
⇒ 🔴 **注释过期**：⭐ 权威 `rtl/top.v:945` 实际是 **`.BAUD_DIV(100)`**（= 500 kbps）。

---

### 2.G ⚠️ 易失数字 / 其它已修

| # | 文件:行（⭐ 改前） | 原文 | 🔴 实测 | ✅ |
|---|---|---|---|---|
| G1 | `ESP32线交接文档-20261001.md:231/239/321` | `🔴 **21 个提交未推**` / `⭐ 21 个提交待推` | ⭐ `git status -sb` = `[ahead 22]`；⭐ 而 `ESP32侧工作计划-20260930.md:5` **自己立了规矩**"以 `ahead N` 为准，⛔ 不写死" | ✅ 已改（⭐ 一律改"以 `git status -sb` 为准"） |
| G2 | `ESP32侧工作计划-20260930.md:98` | `⚠️ 4 个提交压在本地(`0edae6e` / `46fb1b5` / `690d644` / `c6112f9`)` | ⭐ 已过时 | ✅ 已改 |
| G3 | `今晚任务书-20260930.md:72` | `\| **1** \| ⭐ **push 未推提交**（现已 6 个）… \| `ahead/behind = 0 0` \|` | ⭐ 实测 `ahead 22` | ✅ 已改 |
| G4 | `ESP32上机实测问题分析-20260924.md:317` | `\| 7 \| 🔴 **两个 commit 均未 push** —— ⭐ push 需用户同意 \|` | ⭐ 已过时 | ✅ 已改 |
| G5 | `ESP32侧工作计划-20260930.md:181-183`（附录"代码位置"） | `ble_main.c:367`（🔴 CMD 与 RECV 同路径）· `gatt_svc.c:157`（⚠️ STAT 已注册未使用）· `ble_config.h:117`（⚠️ RX 缓冲 1026 B） | ⭐ **三条断言与行号全废**：`ble_main.c:655` = `if (h == s_handle_cmd) {`（⭐ 已剥离）· `gatt_svc.c:180` 起是 `RSP_BY_APP` 修复块 · `ble_config.h:143` = 8192 B | ✅ 已改（⭐ 加删除线 + 逐条实测值） |
| G6 | `今晚任务书-20260930.md:213/234` · `用户裁定结果-20260930.md:144` | `0xABF3`「四个命令」+ 行号 `:606`/`:611`/`:629`/`:634`；⭐ `用户裁定结果` 写 `:629` / `:613` | ⭐ 实测 **7 个命令** @ `:659`/`673`/`691`/`696`/`712`/`724`/`753`；⚠️ `:613` **根本不是 STOP** | ✅ 已改 |
| G7 | `待用户裁定问题清单-20260930.md:150` | `⚠️ 另需：`TX→GPIO5`、`RX→GPIO4`、`115200`。` | ⭐ `ble_config.h:451-452` = `BLE_PIN_HMI_TX 4` / `BLE_PIN_HMI_RX 5` ⇒ ⚠️ **原文没写清是哪一侧 ⇒ 按 ESP32 侧读会正好读反** | ✅ 已改（⭐ 明确两侧） |
| G8 | `ESP32通路总体架构-20260922.md:283` 附近 | `esp32/` 目录树只列 `ble/main` 5 个文件 + `tools/` 3 个脚本 | ⭐ 实测还有 `up_ring.c/.h` · `ws2812.c/.h` · `esp32/uart_test/`；⭐ `selftest_all.py --list` = **19 个工具** | ✅ 已改（⭐ 追加"这棵树仍不完整"块，⛔ 未重画） |
| G9 | `ESP32侧接续准备-20260923.md:44/50/74/107/115` | `UART 1Mbps` · `待改 1 Mbps` · `门限 **160 µs** @1 Mbps` · `FPGA 侧 115200` | ⭐ 两侧均 `500000`；⭐ **门限按 500 k 重算 = 320 µs**（⭐ 16 字节 × 20 µs） | ✅ 已改（⭐ 新增文件头 banner，⛔ 未逐条改写正文） |
| G10 | `上位机与ESP32通路实施计划.md:124/166` | `BAUD_DIV = 434 ⇒ **115200 bps**` · `**115200 8N1**（⚠️ 必须与 `BAUD_DIV=434` 匹配）` | ⭐ 同 B10 | ✅ 已改（⭐ 随 B7 的 banner 一并处理） |

---

## 三、⭐⭐ 单列一类：「文档 A ↔ 文档 B 互相矛盾」

> ⭐ **为什么单列**：⚠️ **两份文档互抄同一句错话时，看起来就像"双重确认"** ——
> 🔴 **这比"单份过期"更难发现**，⭐ 因为读者会本能地用"另一份也这么说"来验证。
> ⭐ 本轮**逐条回到代码/实测**才把它们拆开。

| # | 🔴 矛盾 | 文档 A | 文档 B | ⭐ 真值（⭐ 代码判据） |
|---|---|---|---|---|
| **X1** | ⭐⭐ **`0xABF4` 到底几组** | `ESP32线交接文档-20261001.md:79`「**8 组**」 | `工作计划:31/122` · `再回函:149` · `今晚任务书-20260930:214/235` · `详细执行计划:21` · `交接文档-20260922:16` **六处**都说「**六组 / 221 字节 / 261 B**」 | ⭐ `ble_main.c:419-435` 的 `snprintf` 格式串 = **8 行**（`V1`/`pool`/`ring`/`ble`/`uart`/**`hmi`**/`frame`/`cmd`）⇒ ✅ **A 对、B 错**。⚠️ **六处 B 互相印证，⭐ 但六处都错** |
| **X2** | ⭐⭐ **ESP32 ↔ FPGA 到底通没通** | `ESP32侧再回函-20261001.md:15`「🔴 `PMOD0` 未分配 ⇒ **一根线都没有**」 | `ESP32线交接文档-20261001.md:37-38` 把两条链路打 `✅` 并写成「…→ **FPGA**」 | ⭐ `UART验收报告:3`「⚠️ **不上 FPGA**」· `反向通路验收:5`「**不证明 FPGA 能发**」· `降档请求单:218`「⛔ **不是 FPGA 链路**」⇒ ✅ **A 对、B 错**（⭐ 见 §2.A） |
| **X3** | ⭐ **`0xABF3` 到底几个命令** | `ESP32线交接文档-20261001.md:74-85` 列 **7 个** | `今晚任务书-20260930:213/234` · `详细执行计划:21` · `用户裁定结果:144` 说「四个命令」；⭐ `交接文档-20260922:16`（⭐ 也是 banner）也说「四个」 | ⭐ `ble_main.c:659/673/691/696/712/724/753` ⇒ ✅ **7 个** |
| **X4** | ⭐ **驱动 RX 缓冲多大** | `上行通路缓冲设计:55/59`「**1026 B**」（⭐ 且 §五 说"⛔ 不是把驱动缓冲调大"） | `ble_config.h:117-143` 注释「🔴🔴 RX 缓冲（⭐ 2026-09-30 实测放大）—— **上行丢字节的真正瓶颈在这里**」 | ⭐ `ble_config.h:143` = **8192 B**、`ble_main.c:194` 真装了它 ⇒ ✅ **两者都做了**（⭐ 设计文档的 §五 结论被落地推翻） |
| **X5** | ⭐ **仓库关系** | `esp32/README.md:81-89`「**同一仓库的一个 `git worktree`**」 | `ESP32线交接文档-20261001.md:5/302` 等 **7 处**说"**两个仓库** / ⛔ 不是 `FPGA2026`" | ⭐ `git rev-parse --git-common-dir` = `…/FPGA2026/.git`；⭐ `git worktree list` = 22 个 ⇒ ✅ **A 对、B 错**（⭐ 见 §2.E） |
| **X6** | ⭐ **UART 引脚** | `constr/top.cst`（⭐ **权威**）`:364/366` = `D14`/`D15`（J9） | `constr/top.cst`（⭐ **本 worktree 旧副本**）`:253/255` = `V14`/`U15`（板载）；⭐ 而 `标定链接入:199` · `TX回传:214` 引用的是**旧副本** | ⭐ 权威副本 `:331` 明写 2026-09-24 已搬到 J9 ⇒ ✅ **权威对**（⭐ 见 §2.F） |
| **X7** | ⚠️ **`play_seq` 例化没** | `矛盾裁定单:245`「⚠️ 有文件，⛔ **未例化**」 | `待用户裁定:20`「🔴 **不出声**」 | ⭐ `FPGA2026/rtl/top.v:4412` `// …**尚未例化**（甲）` · `:4429` `.guide_key_i (16'd0), // ⭐ 占位` ⇒ ✅ **两份都对**（⭐ **不是所有"重复"都是错的** —— ⭐ 这条我核实后⛔ 未改，⭐ 见 §四 C5） |
| **X8** | ⚠️ **`0xABF4` 字节数** | `gatt_svc.c:91`「约 **210**」 | `今晚任务书-20260930`「约 **221**」· `工作计划`「**261**」· `交接文档-20261001`「**264**」 | 🔴 **四个数并存，⛔ 无一是权威**（⭐ 要真机发一次 `CMD 0x02` 才能定）⇒ ⭐ 处置 = **⛔ 不再断言字节数**，⭐ 改指 `stat_read.py` 的"组齐全"检查（⭐ 见 §七 U2） |

> 📌 **X8 的教训**：⭐ 当**同一事实出现多个数字**且**都不带判据**时，⭐ **不要挑一个"看起来最像"的** ——
> ⭐ 正确做法是**把断言换成可执行判据**（⭐ 这里是"用工具检查组齐全"）。

---

## 四、⭐⭐ 单列一类：「结论可入库、原始存证不可入库 ⇒ 判据不可复核」

> ⭐ **你点的那条真缺口**。⭐ 我独立复核后确认成立，⭐ **并且它比"行号漂移"严重** ——
> 🔴 **因为行号漂移还能靠 `git log` 追回来，而【从没入库的原始证据】clone 的人根本拿不到。**

### 4.1 🔴 事实（⭐ 实测）

| ⭐ 项 | ⭐ 实测 |
|---|---|
| 报告**引用**了两个原始存证 | ⭐ `esp32/evidence/UART验收报告-20260930.md:6`：`**存证**：`esp32/evidence/uart_test_capture.bin` · `esp32/evidence/uarttest-bootlog-COM29-20260930.log`` |
| 🔴 但它们**不在 git 里** | ⭐ 同文件 `:16` `uart_test_capture.bin` ⇒ `esp32/.gitignore:19` → `*.bin`；⭐ `:17` `uarttest-bootlog-COM29-20260930.log` ⇒ `esp32/.gitignore:46` → `*.log` |
| ⭐ 报告自己**已经点明** | ⭐ `:19`：`⭐⭐ **⇒ 它们在【本地磁盘上存在】，但 `git clone` 的人【拿不到】。**` |
| 🔴 且这是**既有**问题 | ⭐ `:23-31`：交接文档引的 `esp32/evidence/bootlog-COM29-*.log`（⭐ 两份）**从来没被提交过**（⭐ `git log --all -- <path>` 输出为空） |
| ⭐ 反向通路报告同病 | ⭐ `esp32/evidence/反向通路验收-ESP32侧-20260930.md:13`：`⚠️ **本报告的原始日志/抓包【未入库】**` |

### 4.2 ⚠️ 为什么它**削弱了本轮所有"实测"结论**

🔴 **判据链的最后一环是空的**：⭐ 报告说"972 字节零缺口"、"2000 字节逐字节一致"，
⚠️ **但能证明这两句话的字节流不在仓库里** ⇒ ⭐ **别人只能"信报告"，⛔ 不能"复核"**。
⚠️ 同族经验：⭐ `C123`（排错先投**可观测性**）· ⭐ `C83`（探针假绿）—— ⭐ **没有原始数据的"绿"是不可复核的绿。**

### 4.3 ✅ 已有处置（⭐ 报告作者已做，⭐ 我记录并传播）

⭐ `esp32/evidence/UART验收报告-20260930.md:33-42` 的处置是**对的**，⭐ 我把它写进了交接文档口径块：

| 做法 | 理由 |
|---|---|
| ⭐ **关键数据写进 `.md`** | ⭐ Markdown **不受 gitignore 影响** ⇒ ⭐ 结论可长期留存 |
| ⚠️ 原始 `.bin`/`.log` 留本地 | ⚠️ 230 KB 日志 / 近 1 KB 二进制入库收益低；⭐ 且规则是仓库既定的 |

⚠️ **待裁定（⭐ 我不擅改）**：⭐ 是否要给 `esp32/evidence/*.log` 开一个 `!` 例外
（⭐ 就像 `.gitignore:46` 已给 `!sim/evidence/*.log` 开的那样）—— 🔴 **这是仓库策略，⭐ 需用户裁定**。

**✅ 我的处置**：⭐ 在 `ESP32线交接文档-20261001.md` §一 口径块里**写明这条缺口**（⭐ 含 `.gitignore` 行号），
⛔ **未改 `.gitignore`**、⛔ **未改 `esp32/**`**。

> 📌 **⭐ 建议给后续的规矩**（⭐ 写进报告，⭐ 供主会话决定是否落进 `esp32/README.md`）：
> ⭐ **凡"实测验收"结论，⭐ 必须同时给出【可入库】的最小存证** ——
> ⭐ 例如：判据数字 + 前/后各 N 字节的 hex + 长度/校验和，⭐ 直接写进 `.md`；
> ⛔ **不要只引用一个被 gitignore 挡住的 `.bin`/`.log`。**

---

## 五、⭐ 已核实**一致**、⛔ **未改**的断言（⭐ 非空洞性自证）

> ⭐ 目的：证明本轮**不是"见谁都报红"** —— ⭐ 下面这些我**逐字核过、判定正确**，⛔ **一个字都没改**。

### ⭐ 主证 C1 —— `ESP32线交接文档-20261001.md` §二 的「关键事实表」（⭐ 17 行）

**核对方法**：⭐ 把该表 **17 行**逐行取出，⭐ 回到 `esp32/ble/main/ble_config.h` **找定义行**（⛔ 不是看别的文档怎么说）。

| ⭐ 文档断言 | ⭐ 代码依据 | ✅ |
|---|---|---|
| UART1 → FPGA：TX `GPIO17` · RX `GPIO18` · **500000** 8N1 | `ble_config.h:103` `BLE_PIN_UART_TX 17` · `:104` `BLE_PIN_UART_RX 18` · `:84` `BLE_BAUD 500000` | ✅ |
| UART0 日志 `GPIO43`/`GPIO44` · 115200 | `:108` `BLE_PIN_LOG_TX 43` · `:109` `BLE_PIN_LOG_RX 44` | ✅ |
| UART2 → 串口屏：TX `GPIO4` · RX `GPIO5` · 115200 | `:451` `BLE_PIN_HMI_TX 4` · `:452` `BLE_PIN_HMI_RX 5` · `:450` `BLE_HMI_BAUD 115200` | ✅ |
| 起播按键 `GPIO6` | `:425` `BLE_BTN_GPIO 6` | ✅ |
| WS2812 `GPIO48`，必须保持关闭 | `:495` `WS2812_GPIO 48` · `:494` `WS2812_ENABLE 0` · `:502` `WS2812_CLEAR_ON_BOOT 1` | ✅ |
| 下行帧 **9 字节**：`0xA5` + 8 B 大端 | `:45` `#define FRAME_BYTES 9` · `:48` `FRAME_HDR_EVENT 0xA5u` | ✅ |
| 总数帧：帧头 `0x00` + 8 B 大端事件数 | `:51` `#define FRAME_HDR_TOTAL 0x00u` | ✅ |
| 复位标记：9 字节全 `0xA5`（固件吃掉） | `:36` 注释「③ 全 9 字节 = `0xA5` ⇒ 复位标记 ⇒ 丢弃」 | ✅ |
| 音乐时间 PPQN **960** · **120 BPM** ⇒ **1920.003 tick/s** | `:258` `BLE_POOL_DEFAULT_TICK_INC 164927u`；⭐ 复算 `164927 × 50e6 / 2³² = 1920.003` | ✅ |
| GATT：`0xABF0`/`0xABF1`/`0xABF2`/`0xABF3`/`0xABF4` | `:175`-`:179` 五个 `#define` 逐一对上 | ✅ |
| CMD `0x01`/`0x02`/`0x03`/`0x04`/`0x20`/`0x21`/`0x22` 七条 | `ble_main.c:659`/`673`/`691`/`696`/`712`/`724`/`753` | ✅ |
| 起播提前量 `BLE_POOL_LEAD_TICKS = 20000` ≈ **10.4 秒** | `:256` `BLE_POOL_LEAD_TICKS 20000u`；⭐ `20000 / 1920.003 = 10.417 s` | ✅ |
| 相位换算 `f = inc × 50e6 / 2³²` | ⭐ `pool.c` 的 `ev_inc()` 与 `frame_format.py` 的 `phase_inc` 语义一致 | ✅ |

⇒ ⭐ **17 行全部命中，⭐ 无一处需要修改**。

### ⭐ 副证

| # | ⭐ 断言 | ⭐ 核对方法 | ✅ |
|---|---|---|---|
| **C2** | `今晚任务书-20260930.md:241`「音符类 **14 B**、表同步（`0x10`）**68 B**」 | ⭐ `frame_format.py:67` `FRAME_LEN_DEFAULT = 14`；`:68-74` `FRAME_LEN_BY_TYPE = {… T_TABLESYNC: 68}`；⭐ `:208` 自检 `68 = 1+1+1+16×4+1` | ✅ 一致 |
| **C3** | `降档请求单:156/173/180` 引 `pool.c:19`/`:24` | ⭐ 读 `pool.c:19` = `· 500 k 线速 = 50,000 B/s = 5,555 事件/s ⇒ 全速灌，164 ms 就满`；`:24` = `⇒ 一旦本模块"放水"节奏算快了一点点，缓冲就积压 ⇒ 溢出 ⇒ 丢事件` | ✅ **行号与内容都对** |
| **C4** | `ESP32线交接文档-20261001.md:131`「**19 个工具**」 | ⭐ 跑 `python selftest_all.py --list` ⇒ 输出 `会跑 19 个：`（⭐ 逐条列出 19 个） | ✅ |
| **C5** | `待用户裁定:20`「`play_seq` 何时在 `top.v` 例化？⇒ 🔴 不出声」 | ⭐ `FPGA2026/rtl/top.v:4412` `// …**尚未例化**（甲）`；`:4429` `.guide_key_i (16'd0), // ⭐ 占位：待 play_seq（甲）` | ✅ **仍成立**（⭐ **特意保留未改**） |
| **C6** | `ESP32侧回应-FPGA答复-20260930.md:91`「ASCII 流 ✅ 已实现（在 `J9` 上）／`0xA5` 帧 ⚠️ 约定草案（未实现）」 | ⭐ 对 `ESP32侧再回函-20261001.md:161-167`（⭐ 「等冻结后才做」）核 | ✅ 一致（⚠️ FPGA 侧实际状态未独立核，⭐ 见 §六 U4） |
| **C7** | `今晚任务书-20260930.md:211/216/217`（⭐ 500k · `up_ring` · 按键脚 `GPIO6`） | ⭐ `ble_config.h:84`/`:425` · `up_ring.c` 存在性 | ✅ 一致 |
| **C8** | `ESP32侧回应-FPGA答复-20260930.md:30`「`constr/top.cst:137` 明确：`PMOD0`（含 `G21`/`G22`）⇒ 当前未分配」 | ⭐ **权威副本** `FPGA2026/constr/top.cst:137` 逐字一致 | ✅ 一致（⭐ **而且它引的是权威副本**，⛔ 不是旧快照） |
| **C9** | `已知问题与风险清单.md:165`（`K-123`）「`FPGA2026 [main]` 与 `FPGA2026-esp32 [feat/s3-ble]` ⭐ **两个 worktree【共享同一个 `.git`】**」 | ⭐ `git rev-parse --git-common-dir` + `git worktree list` | ✅ **表述正确**（⭐ 本项目**早已写对过** —— ⭐ 见 §三 X5） |

---

## 六、⛔ 存疑 / 没能核实的（⭐ 诚实列出）

### U1 —— ⭐⭐ 「19 个工具 / **317 项** / 0 RED」中的 **317 无法独立复核**（⚠️ **原因是另一个子代理正在并发写 `esp32/tools/evt2midi/`**）

⭐ 我实测跑了 `python selftest_all.py`：

```
合计：19 个工具，257 项 OK，0 项 RED
结论：2 个工具不通过 🔴
---- evt2midi\evt2midi.py (rc=1) ----      SyntaxError: invalid syntax …
---- evt2midi\frame_format.py (rc=1) ----  SyntaxError: invalid syntax …
```

🔴 **但我不把它算作文档错误** —— ⭐ **证据链**：

| ⭐ 判据 | ⭐ 实测 |
|---|---|
| 文件修改时间 | `evt2midi.py` = **2026-10-01 19:00:08** · `frame_format.py` = **19:00:00**（⭐ 与我跑自检**同一分钟**） |
| `git status --short` | ` M esp32/tools/evt2midi/evt2midi.py` · ` M esp32/tools/evt2midi/frame_format.py`（⭐ **只有这两个文件被改**） |
| 报错性质 | ⭐ **`SyntaxError`**（⭐ 引号未闭合）⇒ ⭐ **编辑中间态**，⛔ 不是逻辑缺陷 |

⇒ ⭐ **结论**：🔴 **这是并发写入造成的瞬时状态，⛔ 不能据此判定"文档里的 317 是错的"。**
⭐ **"19 个工具" 部分 ✅ 已独立证实**；⭐ **"317 项 / 0 RED" 我【无法证实也无法证伪】** ⇒ ⛔ **未改**。

> 📌 ⭐ **这正是本任务书警告的"同一项目多副本 / 并发"陷阱** ——
> ⚠️ 如果我"顺手"把 317 改成 257，🔴 **就会把一个正确的历史值改错**，⭐ 而且**下一个接手人会以为工具坏了**。

### U2 —— ⭐ `0xABF4` 的**真实字节数**（⭐ 210 / 221 / 261 / 264 四说并存）

⭐ 要定案必须**真机发一次 `CMD 0x02` 并数读回长度**（⭐ 属需硬件的活）。
⇒ ⭐ **处置**：⛔ 不再断言字节数，⭐ 改指 **`stat_read.py` 的"组齐全"检查**，⭐ 并写清容量真值（`s_val_stat[320]` / `char buf[320]`）。

### U3 —— ⭐ 纯 FPGA 侧的断言（⭐ 需要 FPGA 线信息才能判定）

⭐ 以下**只做了"存在性/例化"级别的核验**，⛔ **未逐条核数值**：

- ⭐ `Fmax 52.372 MHz / 余量 +4.744% / 占用 80.1%`（`ESP32侧再回函:40/134`）—— ⚠️ 需综合报告
- ⭐ `PMOD0` 的 **bank / 电平**"仍是待核"（`:39`）—— ⚠️ 需原理图 + `.cst`（⭐ 注意权威 `.cst:137` 只写"未分配"）
- ⭐ `evt_underrun_o` 语义、`axis→音高` 表大小（⭐ `16×4×2 = 128 B`，`:37`）—— ⚠️ 需 `rtl/` 对应模块
- ⭐ `已知问题与风险清单.md`（149 KB / 189 行）—— ⭐ 主要是 `K-##` 的 FPGA/RTL 条目，⭐ 本轮**只做关键词扫描**，⛔ **未逐条核**

### U4 —— ⭐ `ESP32侧回应-FPGA答复-20260930.md:91` 的"已实现（在 `J9` 上）"

⭐ 判为 ✅ 一致（⭐ 依据 `再回函:161-167` 仍写"等冻结后才做"）。
⚠️ **但"`J9` 上的 ASCII 标定流已实现"是 FPGA 侧的陈述**，⭐ **我未能独立核验** ⇒ ⚠️ 存疑，⛔ 未改。

### U5 —— 🔴 ⭐ `esp32/` 内部的同类错误（⭐ **不是我的写入范围**，⛔ 仅报告）

> ⚠️ 硬边界：⭐ **`esp32/**` 一律只读**（⭐ 另有子代理在写 `esp32/tools/evt2midi/**`）⇒ ⭐ 以下**一个字都没改**。

| # | 位置 | 🔴 问题 |
|---|---|---|
| U5-1 | `esp32/ble/main/ble_config.h:372` | ⭐ 注释仍引 `pool.c:412-413`（⭐ 同 D1 的幽灵行号）—— ⭐ 实测锚点是 `pool.c:461-462` |
| U5-2 | `esp32/ble/main/ble_main.c:1058` | ⭐ 注释仍写 `GPIO —— 板载 BOOT 键（GPIO0）` —— 🔴 而 `ble_config.h:425` 已改 `BLE_BTN_GPIO 6`（⭐ 同文件 `:1331` 用的也是 `BLE_BTN_GPIO`） |
| U5-3 | `esp32/ble/main/gatt_svc.c:90` / `:98` / `ble_main.c:364` | 🔴 **同一个格式串，代码注释里出现「七组」「六组」「六组」三种说法**，⭐ 而实测 `ble_main.c:419-435` 是 **8 行** |
| U5-4 | `esp32/tools/stat_read.py:160` / `:193` | ⭐ 工具提示文字写「六组」，⭐ 而格式串是 **8 行**（⚠️ 不影响判据正确性，⚠️ 只影响可读性） |
| U5-5 | `esp32/tools/evt2midi/README.md` §七 第 2 条 | ⭐ 本任务书已点明的那条（"不解析表同步帧 `0x10`"而代码已解析）—— ⚠️ 归另一个子代理 |
| **U5-6** | ⭐ **`esp32/README.md:81-89`** | 🔴 **覆盖面只到 `rtl/`，⛔ 没覆盖 `constr/`** —— ⚠️ 而 `constr/top.cst` **同样过期且后果更直接**（⭐ 见 §2.F）。⭐ **建议由主会话把覆盖面扩到 `constr/` 并给出机械判据（比 SHA256 / 比大小 / 读权威路径）** |

⭐ **核查：`files/20-代码/**` 里【有没有】重复"不解析表同步帧 `0x10`"这条错话？** ⇒ ✅ **没有**。
⭐ 实测涉及 `0x10` 表同步的文档（`今晚任务书-20261001:71/84/149/162` · `ESP32侧回应:121/150` · `ESP32线交接文档:230`）
⭐ **全部说的是"表帧按 68 B 解析 / 待冻结"** ⇒ ⭐ **本条不属我**。

### U6 —— ⭐ 本 worktree 的 `rtl/` 与 `constr/` 都是旧快照（⚠️ 已按纪律规避）

⭐ 实测：`rtl/top.v`（本 worktree）`:311` = `.BAUD_DIV(50)`（⭐ 1 Mbps，**旧**）vs `FPGA2026/rtl/top.v:702` = `.BAUD_DIV(100)`（⭐ 500 k，**现行**）；
⭐ `constr/top.cst` 17989 B vs **29480 B**（⭐ 见 §2.F）。
⇒ ⭐ **本轮所有 FPGA 侧断言一律以 `FPGA2026`（main worktree）为准**，⛔ 未用本 worktree 的副本下结论。

---

## 七、⭐ 改了什么（逐个文件一句话）

| # | 文件 | 一句话 |
|---|---|---|
| 1 | `ESP32线交接文档-20261001.md` | ⭐ **核心修正**：§一 两行"已通"**降级为"仅 ESP32 侧（CH340/桩）"** + 新增口径块（⭐ ESP32↔FPGA **一次都没跑过**）；⭐ 仓库/worktree 关系改对（`:5`/`:302`/prompt）；⭐ 补 `tag --points-at HEAD` 核对；⭐ `0xABF4` 改「8 组 + ⛔ 字节数别写死」；⭐ 3 处"21 个提交"改"以 `git status -sb` 为准"；⭐ §八 P1 判据落在**真 FPGA** |
| 2 | `反向通路对接单-给FPGA侧-20260930.md` | ⭐ 附录新增 **12 行行号映射表** + "按符号名定位"纪律 |
| 3 | `标定链接入top实施方案-20260923.md` | ⭐ `uart_rx`/`uart_tx` 的 ball 由 `V14`/`U15`(BANK8/6) 改 **`D14`/`D15`(BANK1)**；⭐ 旧 4 行 `.cst` 标"已作废"；⭐ 附权威副本 5 条出处 + SHA 对比；⭐ "另一仓库"改对 |
| 4 | `ESP32侧工作计划-20260930.md` | ⭐ 修 6 处：屏"未接"（3 处）·「六组/261 B 截断」（2 处）· 附录三条废代码位置 · "4 个提交" |
| 5 | `ESP32侧接续准备-20260923.md` | ⭐ 新增文件头 banner：波特率口径全废 + 门限按 500 k 重算为 **320 µs** |
| 6 | `ESP32通路总体架构-20260922.md` | ⭐ 修「起播命令待实现」·「1 Mbps 与我固件一致」· 补目录树缺口（⭐ 漏 `up_ring`/`ws2812`/`uart_test`/16 个工具） |
| 7 | `上位机与ESP32通路实施计划.md` | ⭐ **新增文件头 banner**（3 条）：波特率 500k · UART 已接 `top.v` · ESP32 已落地 |
| 8 | `上行通路缓冲设计-20260930.md` | ⭐ 「驱动 RX 缓冲 1026 B」⇒ **8192 B**，⭐ 并点明与 §五 结论的冲突 |
| 9 | `矛盾裁定单-方案3与模式B-20260930.md` | ⭐ 修 `pool.c:412` 幽灵行号 ·「两个仓库不同步」⇒「同一仓库的两个 worktree 不同步」 |
| 10 | `ESP32侧详细执行计划-20260930.md` | ⭐ 修「屏未接」·「四个命令/六组」+ 行号 · ⭐ **流程插 `git tag --points-at HEAD`** + 新增判据 3b |
| 11 | `TX回传增强设计-20260924.md` | ⭐ 修「`uart_rx`(`V14`) 也是 `BANK8`」这条**已断的交叉验证链**（⭐ 现值 `D14`/BANK1） |
| 12 | `今晚任务书-20260930.md` | ⭐ 修「屏未接」·「需 `uart_tx.v`」·「起播裁定待定」·「六组/221 字节」·「四个命令」·「6 个提交」 |
| 13 | `蓝牙需求分析与实施规划.md` | ⭐ 新增文件头 banner（三环全齐 + 1 Mbps 建议已推翻）；⭐ 修三行状态 + "缺 3 环"结论 |
| 14 | `今晚任务书-20261001.md` | ⭐ **修最严重一条**：CMD `0x10` 由「✅ 完成」⇒「⚠️ **未实现**」；⭐ 另修「屏未接」·「六组/221 B」 |
| 15 | `事件格式改动牵扯面-20260924.md` | ⭐ 「两个仓库都扫」⇒「两个 worktree 都扫」（⭐ 同一仓库） |
| 16 | `待用户裁定问题清单-20260930.md` | ⭐ 修 Q6（`uart_tx.v`）· Q8（16 MB）· Q9（屏）· `pool.c:412-413` · TX/RX 歧义 |
| 17 | `ESP32侧再回函-20261001.md` | ⭐ 修 `pool.c:412` 幽灵行号（2 处）·「六组/256 B 截断」 |
| 18 | `ESP32上机实测问题分析-20260924.md` | ⭐ 修「串口屏未接」·「两个 commit」 |
| 19 | `用户裁定结果-20260930.md` | ⭐ 修 `pool.c:412-413` · `0x03`/`0x04` 行号 `:629`/`:613` ⇒ `:691`/`:696` |
| 20 | `ESP32线当前断点-20260924.md` | ⭐ 「另一个仓库」⇒「另一个分支 / worktree」 |
| 21 | `ESP32通路交接文档-20260922.md` | ⭐ 修**自身 banner** 里的「四个命令 / 六组 221 字节」⇒「七个命令 / 八组」 |
| 22 | `曲谱通路接入设计-20260924.md` | ⭐ 「另一仓库」⇒「同一仓库的另一个 worktree」 |
| 23 | `降档请求单-1M到500k-20260930.md` | ⭐ 「"两个仓库"坑」⇒「同一个仓库的两个 worktree」 |

---

## 八、⭐ 本轮审计的方法论收获（⭐ 供后续复用）

| # | ⭐ 观察 | ⭐ 实证 |
|---|---|---|
| **1** | 🔴 **"同一句错话被抄 N 遍" = 看起来像 N 方确认** | ⭐ 「六组 / 221 字节」**6 处**；⭐ 「屏未接」**9 处**；⭐ `pool.c:412-413` **5 个文件**；⭐ 「两个仓库」**7 处**。⭐ **只有回到代码才能推翻** |
| **2** | ⭐⭐ **"我引用的行号在文件里不存在" = 最强自报警信号**（`C100`） | ⭐ `pool.c:412` 是 `ESP_LOGE` 的参数行；⭐ `ble_main.c:613` 不是 STOP；⭐ 反向通路对接单 **12 个行号全部漂移** |
| **3** | 🔴 **"更正块自己会过期"** | ⭐ `ESP32通路交接文档-20260922.md:16` 的 **2026-10-01 banner** 里就写着已作废的「四个命令 / 六组 221 字节」 |
| **4** | 🔴🔴 **"✅ 已通"可能只是【对端是桩】的通** | ⭐ §2.A：两条链路对端分别是 CH340 与跳线桩，⭐ **真 FPGA 一次都没接过** |
| **5** | ⭐ **"✅ 完成"的标题可能被悄悄换了任务范围** | ⭐ §2.B B1：任务标题是「CMD `0x10`」，⭐ 而正文判据写的是「ESP32 侧零改动」⇒ 🔴 **完成的是另一件事** |
| **6** | 🔴 **同一仓库的两份文档会互相矛盾，而正确的那份【早已存在】** | ⭐ §三 X5：`esp32/README.md:81-89` **早就写对了** "同一仓库的一个 `git worktree`"，⭐ 而 `files/20-代码` 里 **7 处**写成"两个仓库" ⇒ ⭐ **不是"不知道"，是没去对齐** |
| **7** | ⚠️ **并发写入会让"实测"本身不可信** | ⭐ §六 U1：`selftest_all.py` 报 2 个 RED，⭐ 根因是**另一个子代理正在改那两个文件**（⭐ mtime 同一分钟） |
| **8** | ⚠️ **"重复"⛔ 不总是"错"** | ⭐ §三 X7：两份文档都说"`play_seq` 未例化" ⇒ ✅ **实测两份都对**（⭐ 我特意保留未改）—— ⭐ 判据必须是**代码**，⛔ 不是"重复次数" |
| **9** | 🔴 **结论入库 ≠ 判据可复核** | ⭐ §四：`*.bin`/`*.log` 被 `.gitignore` 挡住 ⇒ ⭐ **clone 的人只能"信报告"** |

---

## 九、⭐ 关联

**验收证据（⭐ 只读引用）**
`esp32/evidence/串口屏HMI验收报告-20261001.md` · `esp32/evidence/放水时序验收报告-20260930.md` ·
`esp32/evidence/反向通路验收-ESP32侧-20260930.md` · `esp32/evidence/205帧BLE验收报告-20260930.md` ·
`esp32/evidence/UART验收报告-20260930.md`（⭐ **注意 `:3` 自述"⚠️ 不上 FPGA"**）

**代码判据（⭐ 只读引用）**
`esp32/ble/main/ble_config.h`（⭐ 引脚/波特率/UUID/容量/开关的**唯一权威**）·
`esp32/ble/main/ble_main.c`（⭐ CMD 集 · `cmd_report_status()` · `task_uart_to_ble()`）·
`esp32/ble/main/gatt_svc.c`（⭐ STAT 容量）· `esp32/ble/main/pool.c`（⭐ 起播锚点 `:461-462`）·
`esp32/tools/evt2midi/frame_format.py`（⭐ 帧格式唯一定义处）·
`rtl/top.v` · **`FPGA2026/constr/top.cst`**（⭐ FPGA 侧**权威副本**，⛔ 别用本 worktree 的）

**表述权威出处（⭐ 对齐目标）**
`esp32/README.md:81-89`（⭐ "同一仓库的一个 `git worktree`" —— ⭐ 本项目**早已写对过**）

**上一轮**
`files/20-代码/今晚任务书-20261001.md:87`（⭐ 第二轮审计，18 文件 / 9 处行号漂移）
