hokuu1102/Gowin2026-PolySynth/files/20-代码/用户裁定结果-20260930.md

# ✅ 用户裁定结果（2026-09-30 夜答）

> **用途**：⭐ **把用户对 10 个问题的回答固化下来**，⛔ 不再散落在对话里。
> **上游**：`files/20-代码/待用户裁定问题清单-20260930.md`（⭐ 提问版）
> **工作目录**：`C:\Users\hokuu\Desktop\FPGA\FPGA2026-esp32`

---

## 〇、⭐⭐ 裁定总表

| # | 问题 | ⭐ **用户裁定** | ⚠️ 落到我头上要做什么 |
|---|---|---|---|
| **Q1** | 模式 B 要不要 | ⭐ **要** —— **ESP32 起播**，⭐ **FPGA 负责对齐时序** | ⭐ **新增起播命令**（️ 但见下方🔴更正） |
| **Q2** | 上行载荷格式 | ⚠️ **用户要求解释** ⇒ ⭐ 见 §二 | ⭐ 澄清"哪层跟 FPGA 有关" |
| **Q3** | 不做反向通道 ⇔ 要回传 | ⭐ **要做反向通道** | ✅ **改矛盾的文档**（⭐ 已改 4 处） |
| **Q4** | 会不会超发 | ⚠️ **可能会** ⇒ ⭐ **蓝牙连上就"边灌边发"防满**<br>⭐ **另：连上时点个灯** | ⭐ 放水**已实现**；⭐ **加 LED 指示** |
| **Q5** | PC 侧限速 | ⛔ **不需要** | ⭐ 确认走"ESP32 水池自己放水" |
| **Q6** | `uart_tx.v` | ⭐ **要做**（FPGA 侧） | ⚠️ 转达；⭐ 我们不碰 `rtl/` |
| **Q7** | `play_seq` 例化 | ⭐ **FPGA 那边的事** | ⛔ 不归我们 |
| **Q8** | 映像头 2→16MB | ⭐ **"资源最大化利用没毛病"** | ✅ **已做**（⭐ 16MB，已实测） |
| **Q9** | 串口屏 | ⭐ **随时**（⭐ 可接） | ⭐ 等接线后验 HMI |
| **Q10** | push | ⭐ **可以先 push 一次** | ✅ **执行** |

---

## 一、🔴 Q1 更正 —— "消亚稳态"解决不了对齐问题

> ⭐ **用户原话**：「ESP32 起播，**FPGA 要负责对齐时序，那边消除一下亚稳态应该没问题吧**」

🔴 **"消亚稳态"⛔ 解决不了这个问题** —— ⚠️ **因为根本不是亚稳态问题**：

| 项 | ⭐ 说明 |
|---|---|
| **亚稳态** | ⚠️ 跨时钟域时**某一位**在采样瞬间不确定 ⇒ ⭐ **两级触发器同步即可** |
| 🔴 **这里的真问题** | ⭐ **不是"某位采不准"**，⚠️ **而是"两边从【不同的起点】开始数时间"** |

⭐ **具体**：
- ⭐ ESP32 起播时，把"谱面第 0 拍"锚在**自己的 `esp_timer`** 上（🔴🔴 **2026-10-01 修正：⚠️ 原文写 `pool.c:412-413` ⇒ 【该处不存在这个符号】**；⭐ 实测锚点在 `pool.c:461-462`）
- ⚠️ FPGA 收到第一个事件时，**不知道它对应谱面第几拍** ⇒ 🔴 **无法对齐**
- ⛔ **同步器只能保证"这一位采对了"，⚠️ 保证不了"两边数是同一拍"**

### ✅ 正解（⭐ 靠【格式】，⛔ 不靠同步器）

> ⭐⭐ **上行事件里【带上 `tick`】** ⇒ ⭐ **FPGA 自己就能对齐** ——
> ⭐ 这样"**谁按的键根本不重要**"，✅ **ESP32 起播完全可行**。

⭐⭐ **⇒ 用户的方向（ESP32 起播）是对的**，⚠️ **只是"对齐"的实现手段要写对**：
🔴 **是"事件带 tick"，⛔ 不是"消亚稳态"。**

### ⚠️ 由此推出一条**新的硬要求**（⭐ 给 FPGA 侧）

> ⭐ **上行事件的载荷【必须包含 `tick` 字段】** ——
> ⚠️ 否则 FPGA 无法把动作对齐到谱面时间轴。
> ⭐ 具体位域**由 FPGA 侧定**（⭐ 我们不知道那边有什么可报的），
> ⚠️ **但"必须带 tick"是硬要求。**

---

## 二、⭐ Q2 详解 —— "上行载荷格式跟 FPGA 有关吗？"

⭐ **答：一半有关、一半无关。** ⭐ 它分**两层**：

### 层次一：⭐ **链路层** —— ⚠️ **跟 FPGA 有关**

| 问题 | ⭐ 事实 |
|---|---|
| 走哪条线 | ⭐ **`GPIO18`**（UART1 RX，⭐ 500 kbps 8N1） |
| 波特率谁定 | 🔴 **两边必须一致** —— ⭐ **FPGA 侧定**（`top.v` 的 `BAUD_DIV`） |
| 要不要 **9N 对齐** | ⚠️ **要跟 FPGA 说清**（⭐ 见下） |

⭐ **关于 9N**：
- 🔴 **下行【必须】9 字节对齐** —— ⚠️ 因为 **BLE 不保留 `write()` 边界**（⭐ 一次可能 7 字节，也可能 517 字节）
- ⭐ **上行【不是必需】** —— ⭐ 因为 **ESP32 → FPGA 是【真 UART】**，⭐ **字节边界天然保留**
- ⭐ **但建议还是 9 字节一组**：⭐ FPGA 发的是**事件**，⭐ 每个事件 9 字节 ⇒ ⭐ 对齐了两侧都好处理

### 层次二：⭐ **内容层** —— 🔴 **完全由 FPGA 侧定**

⭐ 即：**那 9 个字节里每一位什么意思？**

🔴 **现状**：⭐ **下行有冻结的位域**（`tick[63:44] inc[43:22] axis[21:18] vel[17:11] kind[10:9] ...`），
⚠️ **而上行【一个字节都没定】**。

⚠️ **为什么我们定不了**：⭐ 上行是 **FPGA → ESP32**，
⭐ 而**"FPGA 有什么可报的"只有 FPGA 侧知道**。

### ⭐⭐ 但**好消息**：ESP32 侧**不必等格式**

| ⭐ 已实现（⛔ 不依赖格式） | ⚠️ 需格式才能做 |
|---|---|
| ⭐ 接收 / 缓冲 / 经 BLE 回传 | ⭐ "按事件丢整帧"（⭐ 现在只能按字节丢） |
| ⭐ 蓄水·放水 / 丢弃记账 | ⭐ 事件语义解析 |

⇒ ⭐ **格式没定⛔ 不挡我们** —— ⭐ **只挡"更聪明的丢弃策略"**。

### ⭐ 一句话

> ⭐ **链路层**（波特率 / 9N）**跟 FPGA 有关**，⚠️ 需确认；
> 🔴 **内容层**（9 字节各位的定义）**由 FPGA 侧定**，⭐ 我们定不了；
> ⭐ **但 ESP32 侧现在就能跑** —— ⭐ 缓冲是透明的。

---

## 三、⭐ Q4 落地 —— "边灌边发防满" + 连上点灯

### 3.1 ⭐ "边灌边发" —— ✅ **已经就是这个行为**

⭐ 用户说「**蓝牙连成功就边灌边发，防止水满**」——
⭐ 这与已实现的**蓄水/放水**模型**完全一致**（⭐ 无需改动）：

| 状态 | ⭐ 行为 |
|---|---|
| ⛔ 未订阅 | ⭐ **蓄水**（只入不出） |
| ✅ 已订阅 | ⭐ **放水**（⭐ **边入边出** ⇒ 正是"防满"） |
| ⚠️ 蓄水满了 | ⭐ **拒绝新的**（保住最早的，⛔ 不挖洞） |

⚠️ **一个细节**：⭐ 我用的触发点是 **CCCD 订阅**，⛔ 不是"物理连接"。
🔴 **原因（实测）**：⭐ 连接建立后 700 ms 内客户端**还没订阅** ⇒
⚠️ 那时发出去的数据**全进虚空**（⭐ PC 侧 0 个包，⭐ 且 `fail=0` 看不出来）。
⇒ ⭐ **"订阅"才是真正的"可以发了"**（⭐ 同 `C106`）。

### 3.2 ⭐ **连上时点灯** —— 🔴🔴 **2026-10-01：该裁定【已被推翻】，灯保持关闭**

⭐ 用户：「**蓝牙连好了可以让灯亮一下，虽然串口屏也有控件**」

> 🔴🔴 **2026-10-01 更正**：⚠️ 本节记录的是 **2026-09-30 夜**的裁定，
> ⭐ 当晚**确实实现过**（`WS2812_ENABLE=1`，用 RMT 自己发时序，⛔ 不依赖外部组件）。
> 🔴 **但 2026-10-01 用户改口：「安全第一」** ⇒ ⭐ **现值 = `WS2812_ENABLE=0` + `WS2812_CLEAR_ON_BOOT=1`**
> （`esp32/ble/main/ble_config.h:494` / `:502`）⇒ ⭐ **每次开机发一次全 0 清锁存，之后永不点亮**。
> 📌 出处：`files/20-代码/今晚任务书-20261001.md:38`「🔴 **灯保持关闭**（⭐ 用户 2026-10-01："安全第一"）—— ⛔ **不要重新打开 WS2812 指示**」
> ⇒ ⭐ **本节的裁定【不再生效】**（⭐ 保留原文以供追溯，⛔ 不删历史）。

⚠️ **发现**：🔴 **当前固件【没有任何 LED 代码】**。
⭐ 板载 RGB LED 在 **`GPIO48`**（⚠️ `ble_config.h:100` 提到 `GPIO38/48` 是板载 RGB）。

⚠️ **需注意**：⭐ `ble_config.h:416` 写着「板载 RGB LED ⛔ 不是（⭐ 本工程明确警告避开 `38/48`）」
⇒ 🔴 **要确认到底用不用它** —— ⚠️ 可能与别的用途冲突。

---

## 四、⚠️ 由裁定引出的**待办**（⭐ 记下来，⛔ 别忘了）

| # | 事项 | ⭐ 归属 | ⚠️ 状态 |
|---|---|---|---|
| **1** | ⭐ **新增 CMD 起播命令**（⭐ Q1 裁定后**不再被阻塞**） | ⭐ **我们** | ✅ **已完成（2026-09-30 夜）** —— 🔴🔴 **2026-10-01 更正**：⚠️ 原标「⏳ 可做」⇒ ⭐ 已落地 **`0x03` 起播 / `0x04` 停止**（⭐ 实测 `case 0x03` @ `esp32/ble/main/ble_main.c:691` · `case 0x04` @ `:696`；🔴🔴 **2026-10-01 修正：⚠️ 原文写 `:629` / `:613` ⇒ 【两处都不是该命令】** —— ⚠️ `:613` 根本不是 STOP；⭐ 复用 `start_action_play/stop`） |
| **2** | ⭐ **连上 BLE 点灯**（亮一下） | ⭐ **我们** | 🔴🔴 **2026-10-01 更正：⛔ 已作废（⭐ 不要做）** —— ⚠️ 原文标「⏳ 可做」⇒ 🔴 **用户已改口「安全第一」** ⇒ ⭐ 现值 `WS2812_ENABLE=0` + `WS2812_CLEAR_ON_BOOT=1`（`esp32/ble/main/ble_config.h:494` / `:502`），⭐ **灯保持关闭**（📌 `files/20-代码/今晚任务书-20261001.md:38`）<br>⚠️ 当晚**确实实现过**，⭐ 但**现已主动关闭**（⭐ 见 §3.2 的更正块） |
| **3** | 🔴 **上行事件必须带 `tick`** | ⭐ **FPGA 侧** | ⚠️ **要转达** |
| **4** | ⭐ **`uart_tx.v`** | ⭐ **FPGA 侧** | ✅ **已存在并已接通（⭐ 反向通路已打通）** —— 🔴🔴 **2026-10-01 更正**：⚠️ 原标「⚠️ 要转达」⇒ ⭐ 该文件已在 `rtl/w3c/uart_tx.v`（⭐ `top.v:918` 例化，`.BAUD_DIV(100)` = 500 k），⭐ 且 **FPGA→ESP32→BLE→PC 2000 字节 round-trip 逐字节一致**（`esp32/evidence/反向通路验收-ESP32侧-20260930.md`） |
| **5** | ⭐ **确认上行 9N 与波特率** | ⭐ **双方** | ⚠️ 要转达 |
| **6** | ⭐ **接串口屏验 HMI** | ⭐ **用户接线** | ⏳ 随时 |
| **7** | ⭐ **push** | ⭐ **我们** | ⏳ 已获同意 |

---

## 附 · 相关文档

`待用户裁定问题清单-20260930.md`（⭐ 提问版）·
`矛盾裁定单-方案3与模式B-20260930.md`（⭐ 已更新裁定结果）·
`反向通路对接单-给FPGA侧-20260930.md`（⭐ 含 Q2 格式问题）
