hokuu1102/Gowin2026-PolySynth/release/20261028/交付审查结论.md

# 交付审查结论

比较固定点为 RC1 源码 409543a；本轮功能实现提交为 4520374 和 5708266，最终成功物理配置为 434b596。审查规范来自 CONTRIBUTING.md，需求来源为 release/20261028/交付要求.md。Standards 与 Spec 分别审查，不把一个维度的通过代替另一个维度。

## Standards

RTL 审查发现 1 项旧说明与新实现不符：EP/FX 回传仍描述为 7/6 字节，且声称冲突时可以丢一个字节。已更正为八字节整帧占用、ready 接受推进与状态队列。对平衡优先树、非二次幂补位、最小索引选择、EP 独立快照、满队列同拍读写的检查未发现阻塞问题；Verilog-2001 编译与 CRLF-aware diff 检查通过。

文档审查发现 5 类现存文件误标为历史未收录：ADC 扩展名、A3 README、ADSR 研究文件、ESP bridge README、BLE CMakeLists。已恢复实际路径并移除错误登记。再按完整路径后缀核对后共补正 8 处；本轮累计 105 处当前路径更正。其余历史/外部/计划材料明确标注，不假装已经找回；引用检查器保持不变，检查通过。

根 README 区分当前与历史；60 项上板记录保持待验。未发现降低时序要求、预填实板通过或以旧日志冒充本次通过的情况。

## Spec

审查发现 1 项 P1：诊断占用只保护 FIFO 入队，未保护物理 UART。实时 14 字节事件与 FXSTAT 同时发送时，注册的 FIFO 启动会撞上 UART 忙状态，吞掉 6 个诊断字节。新增真实 UART 用例复现期望 22 字节、实际 16 字节；字节级日志定位该竞态。

增加实时帧物理占用、诊断八字节占用、探针包起始互斥和异步状态队列后，复测精确收到 live14+FX8 共 22 字节，XOR/元数据和 FX 数值均正确；live14 半包期间发送 Y，空录音拒绝回复在完整帧之外，精确 15 字节，所有占用恢复空闲，无死锁。

指引重构未发现语义扩张：64 槽、32 位重复计数、最小索引 OFF 和原输出周期均保留，12000 拍随机逐周期对照通过。

后续完整回归另发现拒绝通知合并：完整录制导出期间连续 R/L/C 拒绝应各回复一次，实际三次只回一个，期望 53 字节实际 51 字节。原因是新占用门控延迟通知出队，旧单 bit 待发状态合并了请求。5708266 改为 16 位饱和待发计数，保留同时收发语义，并允许导出时入 FIFO、等导出结束后发送。真实 live14+三次拒绝专项从 15 字节恢复到精确 17 字节，所有计数归零；原完整 Hall 录制、双路原子导出、延后探针及逐字节重导出用例也已复测通过。

物理增量审查确认三组试验全部 124 条 IO 约束逐行一致、SDC 和工程器件相同，实际 place_option=0、correct_hold=1；只有算法对照使用 route_option=1。CT2065 是警告，旧 RC1 同范围确曾生成码流，不能据此单独判失败。2616cba 的自动 scope 对照实际报 PR0004 / 380 未布通；最终 434b596 同时解除 scope 与旧回传区域限制，默认算法完成原生布局布线并生成新码流。未放宽时钟要求。

交付流程增量检查补齐本版说明文件，保留旧 RC1 说明；为可选原生产物增加逐项新鲜度校验，为源码压缩包与交付根目录增加白名单。详细 STA 读取 Gowin2026_tr_content.html，不把资源报告的空表当时序通过；使用旧真实报告验证解析后，再读取本次四类非空时序表。选中实际调用的 Tcl 同步纳入源码与复现入口。

单独运行的旧滑音诊断仍有 3 个红结果，不计为通过。它缺失位置/B 轴输入，并把当前复用的端点查表输出钳成同一 target；不符合当前位置跟随契约。其原始 FAIL 日志保留，当前滑音验收使用位置控制器与真实 UART/ADC 端到端用例。

Standards 共 1 项说明问题和 5 类引用问题，已更正；Spec 的 1 项 P1 及完整回归新增的通知合并问题均已有红/绿复测。完整 RTL 回归 233/233 通过，软件 44 个工具、1062 项 OK、0 项 RED。实际新码流已生成，但 setup 最差 -20.414 ns、5424 个违规端点，仍未收敛；hold +0.194 ns、recovery +0.250 ns、removal +0.203 ns。固件来源与文件哈希以最终交付清单为准；本审查不代替上板验收。
