hokuu1102/Gowin2026-PolySynth/release/20261028/文档引用修复记录.md

# 文档引用修复记录

本轮将 105 处可确认的旧目录、扩展名和缺失前缀改为实际仓库路径。未修改检查器，也没有关闭检查范围。

以下条目原来采用当前仓库文件引用形式，但实际是上游资料、工具安装文件、本地临时内容、历史材料或未落地计划。原文已改成明确的文字说明，移除不可用的文件链接。这里不声称相关历史材料已经找回，也不把无法复核的历史测试当成本版通过证据。当前交付判据只使用本轮实际源码、构建报告和测试日志。

| 来源文件 | 原行号 | 原路径文字 | 分类 |
|---|---|---|---|
| `assets/third_party/akwf/SOURCES.md` | 14 | AKWF--Teensy/AKWF_dbass/AKWF_dbass_0050_256.h | upstream path |
| `assets/third_party/akwf/SOURCES.md` | 15 | AKWF--Teensy/AKWF_eguitar/AKWF_eguitar_0015_256.h | upstream path |
| `assets/third_party/akwf/SOURCES.md` | 16 | AKWF--Teensy/AKWF_clavinet/AKWF_clavinet_0005_256.h | upstream path |
| `assets/third_party/akwf/SOURCES.md` | 17 | AKWF--Teensy/AKWF_eorgan/AKWF_eorgan_0020_256.h | upstream path |
| `bringup/32-交接文档-20261016.md` | 253 | en/ | 历史引用，当前未收录 |
| `bringup/32-交接文档-20261016.md` | 253 | evidence/ctrl-board-20261003/ | 历史引用，当前未收录 |
| `bringup/32-交接文档-20261016.md` | 315 | review/效果器运行时-肌肉集团审查-20261015.md | 历史引用，当前未收录 |
| `bringup/32-交接文档-20261016.md` | 316 | review/raw/NIGHT-OWL-fx_delay-20261015.md | 历史引用，当前未收录 |
| `bringup/36-夜战状态报告-20261017.md` | 133 | tools/pnr_watchdog.ps1 | 历史引用，当前未收录 |
| `bringup/hdmi_640x480/README.md` | 115 | src/hdmi2/tmds_channel.sv | 外部参考路径 |
| `bringup/hdmi_640x480/SPEC.md` | 108 | src/hdmi2/tmds_channel.sv | 外部参考路径 |
| `bringup/hdmi_640x480/evidence-h4/RESULT.md` | 89 | initial_cli_failure/ | 历史引用，当前未收录 |
| `bringup/hdmi_640x480/evidence-h4/RESULT.md` | 112 | h4/ | 历史引用，当前未收录 |
| `bringup/hdmi_640x480/evidence-h4/RESULT.md` | 112 | baseline_before/ | 历史引用，当前未收录 |
| `bringup/hdmi_640x480/evidence-h4/RESULT.md` | 112 | baseline_after/ | 历史引用，当前未收录 |
| `bringup/hdmi_640x480/evidence-h4/spec_research.md` | 42 | IDE\doc\CN\SUG283-3.6_Gowin原语用户指南.pdf | 工具安装目录路径 |
| `bringup/hdmi_640x480/evidence-h4/spec_research.md` | 43 | IDE\doc\CN\UG289-2.2.1_Gowin可编程通用管脚(GPIO)用户指南.pdf | 工具安装目录路径 |
| `bringup/hdmi_640x480/evidence-h4/spec_research.md` | 45 | IDE\data\hardware_core\gw5at\prim_syn.v | 工具安装目录路径 |
| `bringup/hdmi_640x480/上板调试记录-20260930.md` | 22 | src/hdmi2/serializer.sv | 外部参考路径 |
| `bringup/hdmi_640x480/上板调试记录-20260930.md` | 52 | bitstreams/ | 历史引用，当前未收录 |
| `evidence/h5/REPORT.md` | 45 | baseline-src/ | 历史引用，当前未收录 |
| `evidence/h5/cls-next-20261004/development-attempts.md` | 12 | synth-final/ | 历史引用，当前未收录 |
| `evidence/h5/cls-next-20261004/development-attempts.md` | 13 | synth-after/ | 历史引用，当前未收录 |
| `evidence/h5/cls-next-20261004/development-attempts.md` | 13 | synth-age-local/ | 历史引用，当前未收录 |
| `evidence/h5/stage2-osc-sweep-share/DESIGN.md` | 94 | tb/w3b/tb_oscillator_sweep_share.sv | 历史引用，当前未收录 |
| `evidence/opt06_main_20261013/README.md` | 76 | worktree/ | 历史引用，当前未收录 |
| `evidence/opt06_main_20261013/README.md` | 79 | af-impl/ | 历史引用，当前未收录 |
| `files/00-总览/BATCH5-音高判据执行方案-20261001.md` | 203 | tb/e2e/tb_e2e_pitch.sv | 历史计划路径，当前未提供 |
| `files/00-总览/T3-复核-总合成-20261001.md` | 127 | files/00-总览/对外问询清单.md | 历史引用，当前未收录 |
| `files/00-总览/T3-复核-总合成-20261001.md` | 127 | bringup/19-变调音高错乱分析-20260930.md | 历史引用，当前未收录 |
| `files/00-总览/T3-复核-组1-20261001.md` | 16 | tb/w3b/tb_transpose_note_manager.sv | 历史引用，当前未收录 |
| `files/00-总览/T3-复核-组1-20261001.md` | 38 | tb/w3c/tb_met_btn_top.sv | 历史引用，当前未收录 |
| `files/00-总览/T3-复核-组1-20261001.md` | 73 | tb/w3b/tb_transpose_note_manager.sv | 历史引用，当前未收录 |
| `files/00-总览/T3-复核-组1-20261001.md` | 76 | tb/w3b/tb_transpose_note_manager.sv | 历史引用，当前未收录 |
| `files/00-总览/T3-复核-组1-20261001.md` | 110 | tb/w3b/tb_transpose_note_manager.sv | 历史引用，当前未收录 |
| `files/00-总览/T3-复核-组2-20261001.md` | 28 | tb/w3b/tb_transpose_note_manager.sv | 历史引用，当前未收录 |
| `files/00-总览/T3-复核-组2-20261001.md` | 30 | bringup/18-池判据按来源失败分析-20260930.md | 历史引用，当前未收录 |
| `files/00-总览/T3-复核-组2-20261001.md` | 181 | bringup/18-池判据按来源失败分析-20260930.md | 历史引用，当前未收录 |
| `files/00-总览/T3-复核-组2-20261001.md` | 295 | tb/w3b/tb_transpose_note_manager.sv | 历史引用，当前未收录 |
| `files/00-总览/T3-复核-组3-20261001.md` | 33 | bringup/17-….md | 历史引用，当前未收录 |
| `files/00-总览/T3-复核-组3-20261001.md` | 35 | bringup/17-….md | 历史引用，当前未收录 |
| `files/00-总览/T3-复核-组3-20261001.md` | 36 | bringup/17-….md | 历史引用，当前未收录 |
| `files/00-总览/T3-复核-组3-20261001.md` | 36 | bringup/19-变调音高错乱分析-20260930.md | 历史引用，当前未收录 |
| `files/00-总览/T3-复核-组3-20261001.md` | 36 | bringup/19-变调音高错乱分析-20260930.md | 历史引用，当前未收录 |
| `files/00-总览/T3-复核-组3-20261001.md` | 36 | bringup/19-变调音高错乱分析-20260930.md | 历史引用，当前未收录 |
| `files/00-总览/T3-复核-组3-20261001.md` | 37 | tb/w3b/tb_transpose_note_manager.sv | 历史引用，当前未收录 |
| `files/00-总览/T3-复核-组3-20261001.md` | 159 | bringup/19-变调音高错乱分析-20260930.md | 历史引用，当前未收录 |
| `files/00-总览/T3-复核-组3-20261001.md` | 175 | tb/w3b/tb_transpose_note_manager.sv | 历史引用，当前未收录 |
| `files/00-总览/T3-复核-组3-20261001.md` | 263 | bringup/19-变调音高错乱分析-20260930.md | 历史引用，当前未收录 |
| `files/00-总览/T3-复核-组4-20261001.md` | 23 | files/00-总览/对外问询清单.md | 历史引用，当前未收录 |
| `files/00-总览/T3-复核-组4-20261001.md` | 23 | files/00-总览/对外问询清单.md | 历史引用，当前未收录 |
| `files/00-总览/T3-复核-组4-20261001.md` | 53 | .vscode/ | 本地路径，非仓库交付文件 |
| `files/00-总览/T3-复核-组4-20261001.md` | 53 | model/step/ | 本地路径，非仓库交付文件 |
| `files/00-总览/T3-复核-组4-20261001.md` | 316 | files/00-总览/对外问询清单.md | 历史引用，当前未收录 |
| `files/00-总览/Worktree处置清单-20261001.md` | 7 | .git/info/squash-history.md | 本地路径，非仓库交付文件 |
| `files/00-总览/交接文档-20260929.md` | 395 | tb/w3c/tb_met_btn_top.sv | 历史引用，当前未收录 |
| `files/00-总览/交接文档-20260929晚.md` | 5 | files/00-总览/交接Prompt-20260929晚.md | 历史引用，当前未收录 |
| `files/00-总览/交接文档-20260930-补遗.md` | 137 | _scratch_k169/ | 历史引用，当前未收录 |
| `files/00-总览/交接文档-20260930-补遗.md` | 137 | _scratch_metfix/ | 历史引用，当前未收录 |
| `files/00-总览/交接文档-20260930.md` | 304 | _scratch_k169/ | 历史引用，当前未收录 |
| `files/00-总览/交接文档-20260930.md` | 304 | _scratch_metfix/ | 历史引用，当前未收录 |
| `files/00-总览/国庆安排-PCB与模型-20261001.md` | 11 | model\pcb\右手板.step | 本地路径，非仓库交付文件 |
| `files/00-总览/未完成工作总账.md` | 957 | files/00-总览/交接Prompt-20260929晚.md | 历史引用，当前未收录 |
| `files/00-总览/未完成工作总账.md` | 1273 | tb\w3c\tb_met_btn_top.sv | 历史引用，当前未收录 |
| `files/00-总览/未完成工作总账.md` | 1286 | tb\w3c\tb_met_btn_top.sv | 历史引用，当前未收录 |
| `files/00-总览/未完成工作总账.md` | 1555 | _scratch_bsram/ | 历史引用，当前未收录 |
| `files/00-总览/赛题对齐-勘误-20261016.md` | 36 | evidence/fx_default_opts_20261015/Gowin2026.rpt.txt | 历史引用，当前未收录 |
| `files/00-总览/赛题对齐-勘误-20261016.md` | 36 | evidence/fx_splitcone_20261015/Gowin2026.rpt.txt | 历史引用，当前未收录 |
| `files/10-硬件/交接-画板专用对话-20261003.md` | 34 | model/ | 本地路径，非仓库交付文件 |
| `files/10-硬件/交接-画板专用对话-20261003.md` | 34 | model/pcb/左手板.step | 本地路径，非仓库交付文件 |
| `files/10-硬件/机械设计总纲-20261002.md` | 122 | \______/ | 历史引用，当前未收录 |
| `files/20-代码/ESP32侧回复-BLE根因与下行贯通-20261014.md` | 3 | FPGA2026-esp32/files/20-代码/上板问题清单-20261013.md | 历史引用，当前未收录 |
| `files/20-代码/ESP32侧答复-9B回传帧与last_seq-20261012.md` | 12 | FPGA2026-esp32/ | 历史引用，当前未收录 |
| `files/20-代码/ESP32侧答复-FPGA上行帧v1.1-20261012.md` | 16 | FPGA2026/ | 历史引用，当前未收录 |
| `files/20-代码/ESP32侧答复-FPGA上行帧v1.1-20261012.md` | 17 | FPGA2026-esp32/files/20-代码/ | 历史引用，当前未收录 |
| `files/20-代码/ESP32侧答复-FPGA上行帧v1.1-20261012.md` | 20 | FPGA2026-esp32/files/20-代码/ | 历史引用，当前未收录 |
| `files/20-代码/ESP32侧答复-FPGA上行帧v1.1-20261012.md` | 30 | FPGA2026-esp32/files/20-代码/ | 历史引用，当前未收录 |
| `files/20-代码/ESP32线交接文档-20261001.md` | 678 | FPGA2026/files/20-代码/ | 历史引用，当前未收录 |
| `files/20-代码/ESP32线交接文档-20261001.md` | 679 | FPGA2026-esp32/files/20-代码/ | 历史引用，当前未收录 |
| `files/20-代码/FPGA侧答复-上行帧v1.1确认-20261012.md` | 13 | FPGA2026-esp32/files/20-代码/ | 历史引用，当前未收录 |
| `files/20-代码/上板清单-Z_merged_base_T5-20261008.md` | 152 | files/00-总览/第三周/第三周组会报告-20261008.md | 历史引用，当前未收录 |
| `files/20-代码/串口屏显示清单与EC11映射-20261016.md` | 662 | rtl/w3c/hmi_status.v | 历史计划路径，当前未提供 |
| `files/20-代码/串口屏显示清单与EC11映射-20261016.md` | 1402 | tb/w3c/tb_hmi_status.sv | 历史引用，当前未收录 |
| `files/20-代码/优化记录-evt_merge-20261002.md` | 52 | pnr-impl/ | 历史引用，当前未收录 |
| `files/20-代码/已知问题与风险清单.md` | 227 | IDE/data/device/device_info.csv | 工具安装目录路径 |
| `files/20-代码/延音踏板语义-实施方案-20261004.md` | 107 | tb/top/tb_sustain_pedal.sv | 历史计划路径，当前未提供 |
| `files/20-代码/控制板16键功能映射-20261013.md` | 358 | files/10-硬件/控制板PCB-20261003.md | 历史引用，当前未收录 |
| `files/20-代码/控制板16键功能映射-20261013.md` | 359 | files/10-硬件/控制板PCB-20261003.md | 历史引用，当前未收录 |
| `files/20-代码/文档取代关系索引.md` | 104 | 00-总览/README.md | 历史引用，当前未收录 |
| `files/20-代码/节拍器加回-实施记录-20260928.md` | 203 | tb/w3c/tb_met_btn_top.sv | 历史引用，当前未收录 |
| `files/20-代码/逻辑优化审计-20260930.md` | 265 | cmd_cnt_o/ | 信号表达式，非文件路径 |
| `fix_evidence/修复结果-20261020.md` | 17 | ../../rtl/ | 路径规范化示例 |
| `review/raw/ANVIL-08.md` | 131 | %TEMP%\anvil08_probe\t1.v | 本地临时路径 |
| `review/raw/ANVIL-08.md` | 284 | %TEMP%\anvil08_probe\t5.v | 本地临时路径 |
| `review/raw/ANVIL-08.md` | 433 | %TEMP%\anvil08_probe\t2.v | 本地临时路径 |
| `review/raw/ANVIL-08.md` | 537 | %TEMP%\anvil08_probe\t4.v | 本地临时路径 |
| `review/raw/ANVIL-08.md` | 1059 | %TEMP%\anvil08_probe\t3.v | 本地临时路径 |
| `review/raw/ANVIL-10.md` | 1063 | rtl/w3c/hex_char.v | 历史计划路径，当前未提供 |
| `review/raw/ANVIL-11.md` | 140 | tb/w3c/tb_tlc5916_bank_seq.sv | 历史计划路径，当前未提供 |
| `review/raw/ANVIL-11.md` | 602 | tb/w3a/tb_ws2812_partial.sv | 历史计划路径，当前未提供 |
| `review/raw/ANVIL-12.md` | 500 | tb/sync_input/ | 历史引用，当前未收录 |
| `review/raw/ANVIL-12.md` | 517 | tb/sync_input/tb_sync_input.sv | 历史计划路径，当前未提供 |
| `review/raw/TORCH-1.md` | 998 | gate_r/env_active_r/ | 信号表达式，非文件路径 |
| `review/raw/TORCH-3.md` | 261 | tb/cdc/tb_reset_release_order.sv | 历史计划路径，当前未提供 |
| `review/raw/TORCH-3.md` | 894 | tb/w3b/tb_note_manager_t3.sv | 历史引用，当前未收录 |
| `review/spec/report.md` | 19 | review/spec/venv/ | 本地路径，非仓库交付文件 |
| `review/时序与逻辑审查-20261009.md` | 11207 | files/10-硬件/Console拓展板接线需求-20261003.md | 历史引用，当前未收录 |
| `sim/evidence/a3-drum-raw-20261008/README.md` | 42 | tb/w3b/tb_osc_drum_raw.sv | 历史引用，当前未收录 |
| `sim/evidence/bpm-uart-20261011/README.md` | 137 | tb/w3c/tb_play_seq_bpm.sv | 历史计划路径，当前未提供 |
| `sim/evidence/esp32-uart-20261011/README.md` | 3 | files/10-硬件/Console拓展板接线需求-20261003.md | 历史引用，当前未收录 |
| `sim/evidence/evt_merge-narrow-20261002/README.md` | 11 | pnr-impl/ | 历史引用，当前未收录 |
| `sim/evidence/rightboard-vibrato-fix-20261008/README.md` | 280 | tb/w3b/tb_osc_drum_raw.sv | 历史引用，当前未收录 |
