hokuu1102/Gowin2026-PolySynth/files/20-代码/串口屏-RTL改动说明-给队友-20261102.md

# 串口屏配套 RTL 改动说明（给 RTL 负责人）

> **日期**：2026-11-02
> **配对屏工程**：`p0.HMI`（TJC X2 7"，1024×600，`Program.s` 里 `baud=115200`）
> **基准代码**：`origin/codex/delivery-hmi-checklist-20261102` @ **0da99f09**（2026-11-02）
> ⚠️ 行号以此为准；你若在 `wip/c-uartui` 上改，行号可能差几行，按代码内容找。
>
> **本文件收录了 2026-11-02 联调中**用户提出的全部问题**，包括已经改好的和还没改的。

---

## 〇、状态总表（一眼看全）
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
