hokuu1102/Gowin2026-PolySynth/esp32/evidence/回传可视化上位机-截图-20261012.png

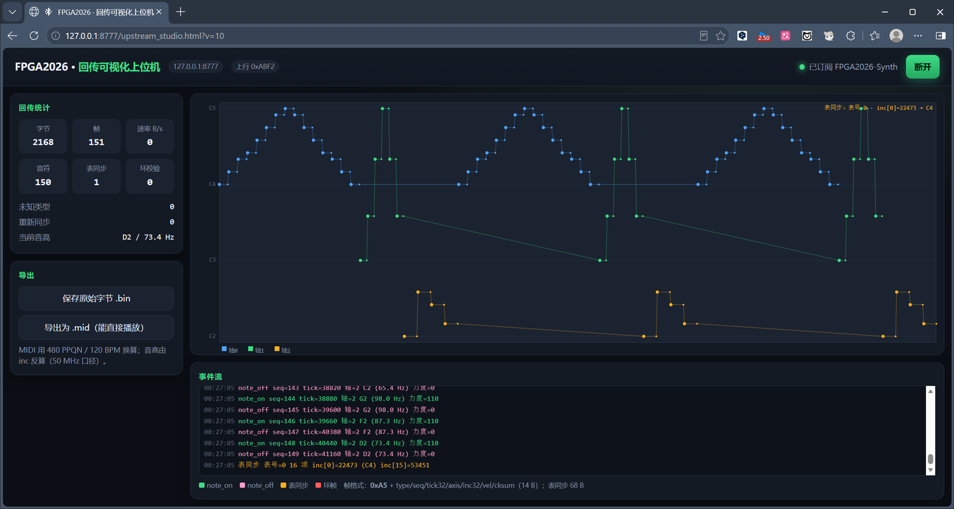
esp32/evidence/回传可视化上位机-截图-20261012.png
