hokuu1102/Gowin2026-PolySynth/esp32/evidence/曲谱上位机-截图-20261011.png

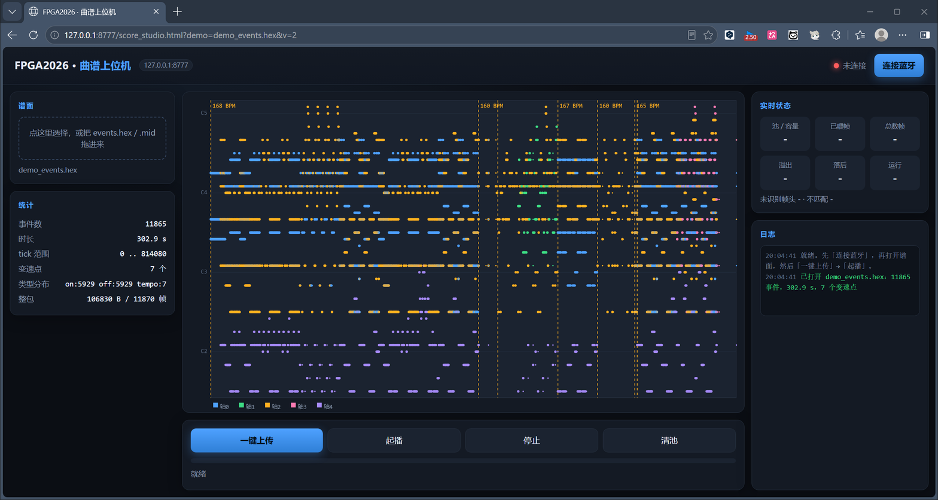
esp32/evidence/曲谱上位机-截图-20261011.png
