hokuu1102/Gowin2026-PolySynth/evidence/h5/triggered-scope-20261002/frameA.png

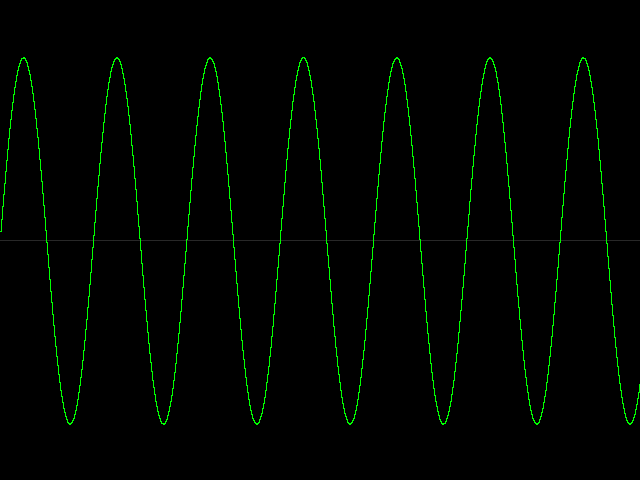
evidence/h5/triggered-scope-20261002/frameA.png
