hokuu1102/Gowin2026-PolySynth/files/10-硬件/7x2对齐双排网格的两种映射_钢琴模式与指板模式.png

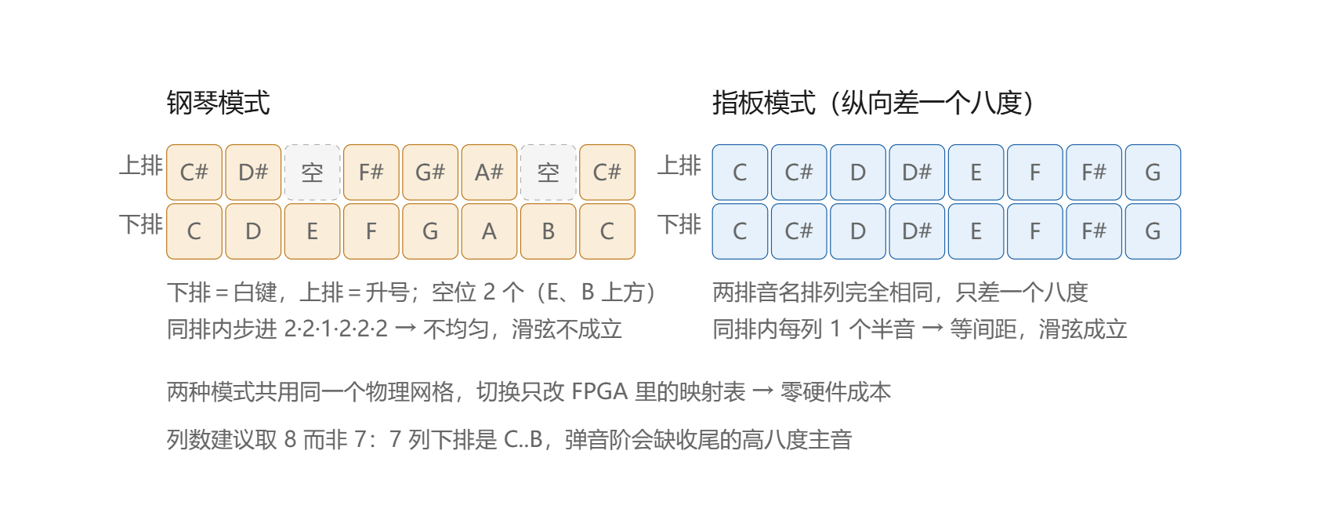
files/10-硬件/7x2对齐双排网格的两种映射_钢琴模式与指板模式.png
