hokuu1102/Gowin2026-PolySynth/files/10-硬件/两块2x4拼成2x8的跨缝间距修正.png

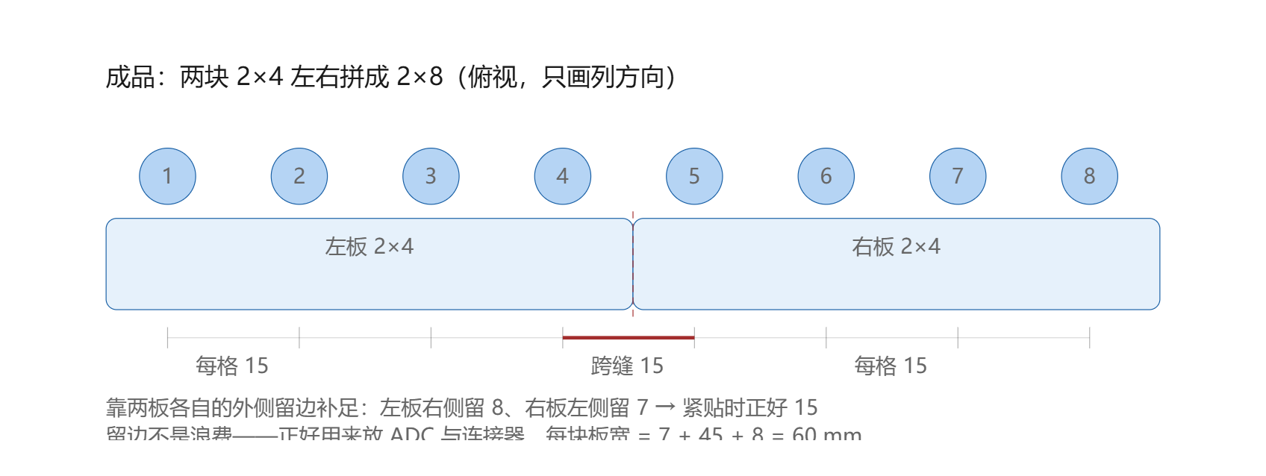
files/10-硬件/两块2x4拼成2x8的跨缝间距修正.png
