hokuu1102/Gowin2026-PolySynth/files/10-硬件/霍尔键位映射图.drawio.png

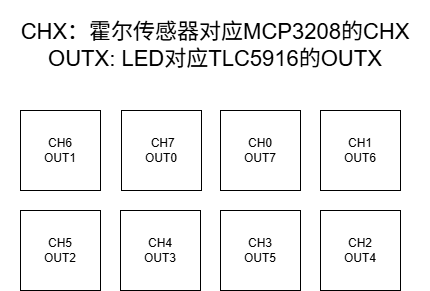
files/10-硬件/霍尔键位映射图.drawio.png
