hokuu1102/Gowin2026-PolySynth/files/40-参考资料/常见高云fpga使用问题汇总.jpg

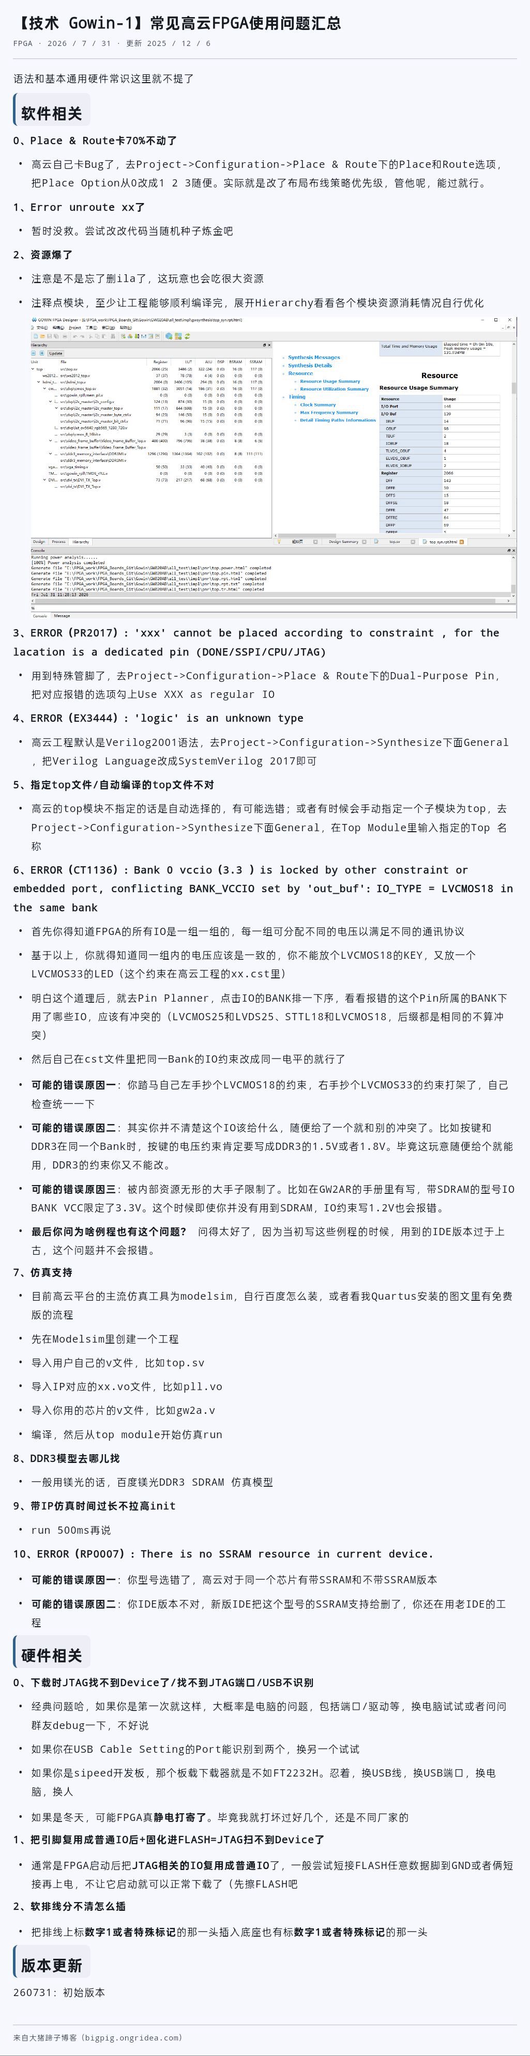
files/40-参考资料/常见高云fpga使用问题汇总.jpg
