hokuu1102/Gowin2026-PolySynth/sim/evidence/i2s_tx_l_spectrum.png

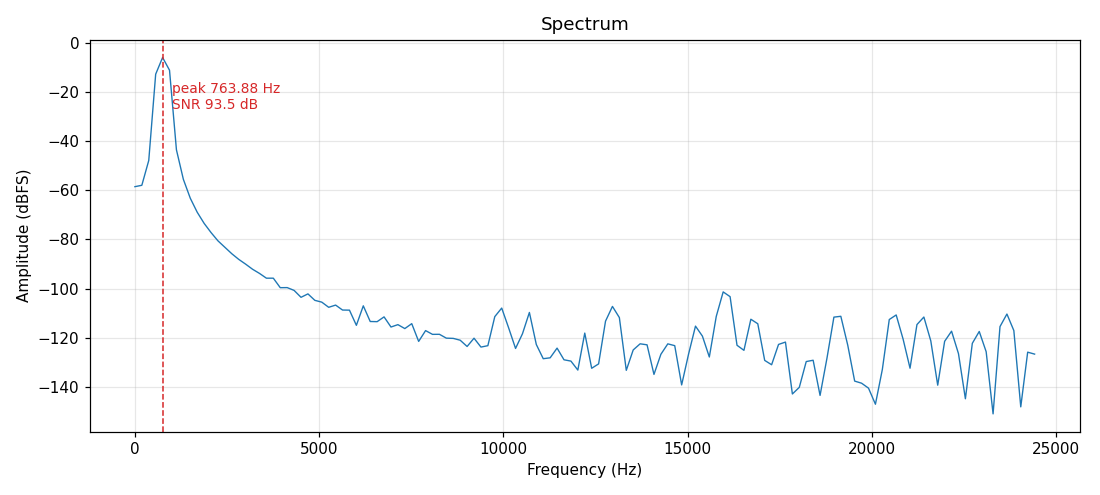
sim/evidence/i2s_tx_l_spectrum.png
