hokuu1102/Gowin2026-PolySynth/sim/evidence/selftest_sine_1k_spectrum.png

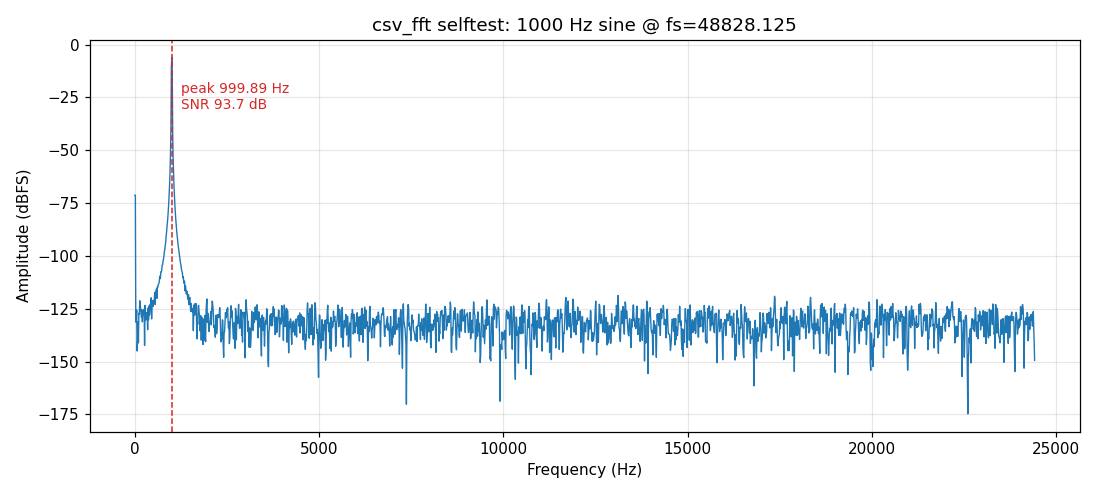
sim/evidence/selftest_sine_1k_spectrum.png
