hokuu1102/Gowin2026-PolySynth/hmi7/串口屏v3-搭建清单-20261029.md

# 🖥️ 串口屏 v3 搭建清单 · TJC X2 7寸 1024×600（最终版）

> **屏**：淘晶驰 TJC X2，7 寸，1024×600，接 **FPGA 板载 UART**
> **上位机**：USART HMI（TJC 版）
> **日期**：2026-10-29（丙）· 本版 = v2 修订版的**干净终版**，可直接照做
> **配套 RTL**：`rtl/w3c/uart_ui.v`（回显 FSM **57 字段全动态**：非心跳帧 **56** + 心跳 1；
> 三件套 0x88 全量重发 / 0x19 翻转 / 0x1B 八度循环 + **§八收口三件**：t_loop 三态配色 /
> led_* 状态灯 / page1 动态字段，tb **312 checks PASS**，2026-10-29 深夜收口；
> **2026-10-30 补**：⭐ 触摸控件 3 = 音色循环（b_timbre，屏上切音色闭环）⇒ tb 317 checks PASS）
> **2026-10-31 补**：⭐⭐ **page0 控制面板化**：触摸控件 4..14 = 滑音/鼓机/打鼓/移调±/循环录播清/档位/BPM±
> （11 个新热区按钮，全部真控 FPGA 寄存器 + 回显自动闭环）⇒ tb **340 checks PASS**。
> **2026-10-31 深夜补**：⭐⭐⭐ **卡片 B/D 重构 + 状态灯 + 实时上行开关**：鼓机五态（关/Pattern I..IV）、
> t_kd 新文案、卡片 D 废除 z_pd/z_vd 仪表改双仓深度+速率进度条组、p_slide/p_bpm 状态灯、
> b_uplink 实时上行开关（控件 15）⇒ tb **392 checks PASS**。
> **历史**：12 处修正过程见 `串口屏v2-修订版-20261029.md`（本文件不再重复）

---

## 一、⭐ 建工程（第一步）

| 项 | 填什么 |
|---|---|
| **设备型号** | 按实物选（TJC X2 系列 1024×600） |
| **方向** | 横屏 1024 × 600 |
| ⭐⭐ **工程编码** | 🔴 **`UTF-8`**（⛔ 不是 GB2312/GBK；⛔ 选错不能事后改） |
| **波特率** | 🔴 **115200**（= FPGA 板载口 BAUD_DIV=434，2026-10-28 改档后） |
| **页面** | `page0`（演奏看板）+ `page1`（效果器链） |

> ⭐ 页面背景色：page0 / page1 属性里设 **63454**（#F0F3F6 浅灰底）。

---

## 二、⭐ 字库（6 档，字体选粗）

| 字库 | 字号 | 字体（字库制作工具里选） | 勾"字体加粗" | 用在哪 |
|---|---|---|---|---|
| 库① | **12** | ⭐ **微软雅黑** | ❌ 不勾 | 各 l_ 标签（含 l_vp_title/l_vv_title）、t_conn、t_lock、t_lock_info、t_fx_route、t_fx_uart、l_test |
| 库② | **16** | ⭐ **微软雅黑** | ✅ 勾 | t_vol、t_pedal、t_gear、t_hdmi、t_pd、t_vd、t_pr、t_vr、b_uplink、底部 t_*_st、t1、b_oct、b_mode、b_test、b_timbre、b_slide、b_drum、b_kd、b_tr_dn、b_tr_up、b_bpm_dn、b_bpm_up、b_rec、b_play、b_clear、b_gear、cur、gr |
| 库③ | **20** | ⭐ **微软雅黑** | ✅ 勾 | t_mode、t_trans、t_slide、t_loop |
| 库④ | **24** | ⭐ **微软雅黑** | ✅ 勾 | t_drum |
| 库⑤ | **32** | ⭐ **思源黑体 Heavy** | —（本身够粗） | t_timbre |
| 库⑥ | **48** | ⭐ **思源黑体 Heavy** | —（本身够粗） | t_bpm 巨字 |

> ⭐ **选型理由**（设计图 = GitHub 风格浅色工业风 = 现代无衬线粗体）：
> - 正文 12~24：**微软雅黑 + 勾加粗**——字重均匀、小字号清晰
> - 巨字 32/48：**思源黑体 Heavy**——字面宽、笔画厚，"BASS"/"120" 的海报感
> - 备选：没有思源黑体就全套微软雅黑+加粗；⛔ **别选宋体/楷体/隶书/幼圆**
> - ✅ "字体抗锯齿"保持勾选
> ⚠️ 6 个库的字符集**统一**（见 §七，一份字符集生成 6 次）。

---

## 三、Page 0：演奏与综合控制看板

### 0. 底板（⭐ 最先建，白色卡片底）

| 控件名 | 类型 | 坐标 (x,y,w,h) | 说明 |
|---|---|---|---|
| `bg_a` | 文本（空文字，bco=65535） | (16, 48, 484, 222) | 卡片 A 底板 |
| `bg_b` | 文本（空文字，bco=65535） | (524, 48, 484, 222) | 卡片 B 底板 |
| `bg_c` | 文本（空文字，bco=65535） | (16, 280, 484, 230) | 卡片 C 底板 |
| `bg_d` | 文本（空文字，bco=65535） | (524, 280, 484, 230) | 卡片 D 底板 |

### 1. 顶栏与系统状态（y: 0..40）

| 控件名 | 类型 | 坐标 | 默认内容 | 前景/背景 (RGB565) | 字库 | 说明 |
|---|---|---|---|---|---|---|
| `l_title` | 文本 | (20, 8, 480, 26) | `FPGA DUAL-AXIS SYNTHESIZER CONSOLE` | 9509 / 透明 | ① | 静态 |
| `t_conn` | 文本 | (760, 10, 160, 22) | `UART 115.2K [ONLINE]` | 2459 / 透明 | ① | 静态 |
| `p_hb` | 🔴 **双态按钮** | (940, 15, 10, 10) | sta=图片，pic=**0**(灰) / pic2=**1**(绿)，val=0 | — | — | ⭐ 心跳点，事件见 §六 |

### 2. 卡片 A：演奏核心区

| 控件名 | 类型 | 坐标 | 默认内容 | 前景/背景 | 字库 | 说明 |
|---|---|---|---|---|---|---|
| `l_card_a` | 文本 | (32, 58, 300, 20) | `CORE PERFORMANCE / 演奏核心` | 22477 / 透明 | ① | 静态 |
| `t_timbre` | 文本 | (32, 86, 210, 48) | `BASS` | 9509 / 63455 | ⑤ | FPGA 回显：BASS/GUITAR/PIANO/PAD |
| 🔥 `b_timbre` | **按钮** | (168, 94, 70, 36) | `切音色` | 2459 / 65535 | ② | **叠放在 t_timbre 右端上层**（主用，同 b_mode 做法），事件见 §六 · ⭐ 2026-10-30 落地。**点完后 t_timbre 大字自动同步变**：FPGA 回显帧驱动，屏不用记账（⚠️ 需重出位流才在板上生效；模拟器单机只出 HEX 不变字，属正常） |
| ⭐ `h_timbre`（可选） | **热区** | (32, 86, 210, 48) | （透明，无内容） | — | — | 可选增强：盖住整个 t_timbre，点 BASS 大字**任意处**也可切（与 b_timbre 发同一帧，二选一或并存均可；并存时热区后建于按钮之后即接管触摸；热区后建才在上层） |
| `t_mode` | 文本 | (254, 86, 232, 48) | `指板模式 [FRET]` | 2459 / 63455 | ③ | FPGA 回显 |
| 🔴 `b_mode` | **按钮** | (400, 94, 80, 36) | `切换` | 2459 / 65535 | ② | **叠放在 t_mode 右端上层**，触控翻转模式，事件见 §六 |
| `t_base` | 🔴 **文本** | (32, 144, 454, 48) | `基准音: C4 (最低音 C3)` | 9509 / 63455 | ③ | FPGA 回显，**纯显示不可点** |
| `b_oct` | 🔴 **按钮** | (374, 150, 108, 36) | `点击切八度 ↕` | 2459 / 65535 | ② | **叠放在 t_base 右端上层**，事件见 §六 |
| `l_trans` | 文本 | (32, 198, 210, 16) | `半音变调` | 22477 / 透明 | ① | 静态小标签（⭐ 2026-10-30 补：UI 效果图有此行小灰字，此前控件表漏列） |
| `t_trans` | 文本 | (32, 216, 210, 48) | `0 SEMI (原调)` | 55264 / 63455 | ③ | FPGA 回显（坐标较旧版下移给小标签让位）：0 ⇒ `0 SEMI (原调)`，±N ⇒ `+N SEMI` / `-N SEMI`（ASCII 减号），范围 −12~+12 |
| 🔥 `b_tr_dn` | **按钮** | (110, 222, 60, 36) | `-1` | 2459 / 65535 | ② | 叠放在 t_trans 右端上层，移调 −1 半音（控件 8，⭐ 2026-10-31；⚠️ 文案用 ASCII 减号，⛔ 不用 U+2212，字库没有） |
| 🔥 `b_tr_up` | **按钮** | (176, 222, 60, 36) | `+1` | 2459 / 65535 | ② | 叠放在 t_trans 右端上层，移调 +1 半音（控件 7，⭐ 2026-10-31） |
| `l_slide` | 文本 | (254, 198, 232, 16) | `滑音机制` | 22477 / 透明 | ① | 静态小标签（⭐ 2026-10-30 补，同 l_trans） |
| `t_slide` | 文本 | (254, 216, 232, 48) | `开启 (GLIDE ON)` | 6822 / 63455 | ③ | FPGA 回显：开 ⇒ `开启 (GLIDE ON)`，关 ⇒ `关闭 (GLIDE OFF)` |
| 🔥 `b_slide` | **按钮** | (410, 222, 68, 36) | `滑音` | 2459 / 65535 | ② | 叠放在 t_slide 右端上层，滑音开/关（控件 4，⭐ 2026-10-31） |
| ⭐ `p_slide` | 🔴 **双态按钮** | (480, 222, 10, 10) | sta=图片，pic=**0**(灰)/pic2=**1**(绿)，val=0 | — | — | ⭐ 滑音状态灯（绿点，⭐ 2026-10-31 落地）：FPGA 回显 `p_slide.val=`，与 t_slide 同源同发 |

> ⭐ **同类规则**：FPGA 回显的行一律**文本控件**；要触控就在右端**叠放小按钮**（后建控件在上层吃触摸）。
>
> ⭐ **想让整块回显文字都可点**（如点 BASS 大字切音色）：用**热区**控件盖住该文本并**后建**——
> 热区透明不遮字、只吃触摸；⛔ 不要用不透明按钮盖满整行，会把 FPGA 回显的字盖掉。
>
> ⛔ **两个不可屏控字段（⭐ 2026-10-31 审计定位，非缺实现）**：
> · `t_vol` —— 主音量在 FPGA 侧**无现有命令路径**（`master_mix` 的 gain 固定 0x7FFF，音量旋钮未落地）⇒
>   屏控它需要先把 gain 寄存器化（涉及音频链增益），**遗留决策项待定**。
> · `t_pedal` —— 物理踏板输入监视（PMOD 实体踏板），**设计上就不该屏控**（屏不能代替踩踏板）。
>
> ⭐ **小标签规则（⭐ 2026-10-30 补）**：UI 效果图里部分数值块上方还有一行 12px 小灰字标签，
> 共 4 处，对应 4 个**静态文本**控件（22477 灰 / 透明，库①）：
> · 卡片 A：`l_trans`（半音变调）、`l_slide`（滑音机制）—— 见上表已补；
> · 卡片 B：`l_bpm`（BPM 速度）、`l_drum`（伴奏鼓机 (罗马律动)）—— 见 §三-3 已补。
> 其余字段的小标题**已含在回显文字本身**（如 `基准音: C4`、`键盘打鼓: 关闭`、`音高颤音: 25%`），不用另建控件。
> ⭐ **效果图数值右侧的小圆点（⭐ 2026-10-31 已落地为状态灯）**：
> · `p_slide`（滑音旁绿点）＝双态按钮，`.val=0/1` 随 t_slide **同源同发**（滑音开=绿/关=灰）；
> · `p_bpm`（BPM 旁橙点）＝双态按钮，`.val` 随节拍脉冲 `beat_i` **每拍翻转 0/1**（橙点随节拍闪烁）。
> 两个都是 FPGA 回显帧驱动（`.val=` 帧型），控件见 §三-2/§三-3 表，圆点图见 `tools/hb_dots/`（p_bpm 用橙点档，见 §八-5）。

### 3. 卡片 B：节奏与循环区

| 控件名 | 类型 | 坐标 | 默认内容 | 前景/背景 | 字库 | 说明 |
|---|---|---|---|---|---|---|
| `l_card_b` | 文本 | (540, 58, 360, 20) | `RHYTHM & LOOPER / 节奏循环 (无节拍器)` | 22477 / 透明 | ① | 静态 |
| `l_bpm` | 文本 | (540, 84, 180, 14) | `BPM 速度` | 22477 / 透明 | ① | 静态小标签（⭐ 2026-10-30 补：UI 效果图有此行小灰字，此前漏列） |
| `l_drum` | 文本 | (732, 84, 260, 14) | `伴奏鼓机 (罗马律动)` | 22477 / 透明 | ① | 静态小标签（⭐ 2026-10-30 补，同 l_bpm；字均在 §七 153 字集内） |
| `t_bpm` | 文本 | (540, 100, 180, 58) | `120` | 9509 / 63455 | ⑥ | FPGA 回显，48px 巨字（坐标下移给小标签让位） |
| 🔥 `b_bpm_dn` | **按钮** | (552, 112, 56, 36) | `-5` | 2459 / 65535 | ② | 叠放在 t_bpm 左端上层，BPM −5（控件 14，40 下限，⭐ 2026-10-31；⚠️ 文案用 ASCII 减号） |
| 🔥 `b_bpm_up` | **按钮** | (652, 112, 56, 36) | `+5` | 2459 / 65535 | ② | 叠放在 t_bpm 右端上层，BPM +5（控件 13，240 上限，⭐ 2026-10-31） |
| ⭐ `p_bpm` | 🔴 **双态按钮** | (716, 112, 10, 10) | sta=图片，pic=**0**(灰)/pic2=**1**(橙)，val=0 | — | — | ⭐ 节拍状态灯（橙点，⭐ 2026-10-31 落地）：FPGA 回显 `p_bpm.val=`，随节拍脉冲每拍翻转 0/1（橙点随节拍闪） |
| `t_drum` | 文本 | (732, 100, 260, 58) | `Pattern I` | 2459 / 63455 | ④ | FPGA 回显，五态：`关` / `Pattern I` / `II` / `III` / `IV`（⭐ 2026-10-31 落地，见 §六 控件 5 五态循环；默认文字仅上电初始值，上电即被回显覆盖） |
| 🔥 `b_drum` | **按钮** | (920, 110, 64, 40) | `节奏` | 2459 / 65535 | ② | 叠放在 t_drum 右端上层，节奏型下一（控件 5，五态循环 `I→II→III→IV→关→I`，⭐ 2026-10-31 落地） |
| `t_loop` | 文本 | (540, 160, 452, 46) | `● 循环录音中 REC` | 65535 / 52517 | ③ | FPGA 回显文字 + **四态配色**（`.bco=`/`.pco=` 色帧已落地，见 §八-2） |
| 🔥 `b_rec` | **按钮** | (736, 166, 70, 34) | `●录` | 2459 / 65535 | ② | 叠放在 t_loop 右端上层，录/停切换（控件 9，⭐ 2026-10-31） |
| 🔥 `b_play` | **按钮** | (812, 166, 70, 34) | `►播` | 2459 / 65535 | ② | 同上，播/停切换（控件 10，⭐ 2026-10-31；⚠️ 用 ► U+25BA，⛔ 不用 ▶ U+25B6，字库没有） |
| 🔥 `b_clear` | **按钮** | (888, 166, 84, 34) | `清空` | 2459 / 52517 | ② | 同上，清空该层（控件 11，⭐ 2026-10-31） |
| `t_kd` | 文本 | (540, 214, 452, 40) | `打鼓: 关闭 [音符演奏]` | 9509 / 63455 | ② | FPGA 回显：开 ⇒ `打鼓: 开启 [键位打鼓]`，关 ⇒ `打鼓: 关闭 [音符演奏]`（⭐ 2026-10-31 新文案，缩窄到 220px 后前缀砍成 2 字） |
| 🔥 `b_kd` | **按钮** | (912, 218, 72, 32) | `打鼓` | 2459 / 65535 | ② | 叠放在 t_kd 右端上层，键盘打鼓开/关（控件 6，⭐ 2026-10-31） |
| ⭐ `b_uplink` | 🔴 **按钮** | (540, 258, 452, 36) | `● 实时上行: 开启` | 2459 / 65535 | ② | ⭐ **实时上行开关**（控件 15，⭐ 2026-10-31 落地）：触摸翻转 FPGA `uplink_sw_o`，回显 `.txt=` 驱动文字 `● 实时上行: 开启/关闭`（⚠️ 待实物核对坐标） |

### 4. 卡片 C：物理外设监视区

| 控件名 | 类型 | 坐标 | 默认内容 | 前景/背景 | 字库 | 说明 |
|---|---|---|---|---|---|---|
| `l_card_c` | 文本 | (32, 290, 320, 20) | `HARDWARE PERIPHERALS / 物理外设监视` | 22477 / 透明 | ① | 静态 |
| `t_vol` | 文本 | (32, 320, 120, 26) | `主音量: 85%` | 9509 / 透明 | ② | FPGA 回显 |
| `j_vol` | 进度条 | (160, 326, 326, 14) | val=85，🔴 **maxval=100** | 前景 6822 / 背景 — | — | FPGA 回显 `j_vol.val=` |
| `t_pedal` | 文本 | (32, 358, 454, 42) | `[PEDAL 延音踏板: 踩下使能]` | 6822 / 63455 | ② | FPGA 回显 |
| `t_gear` | 文本 | (32, 410, 300, 42) | `推子控制: 档 1 [音高颤音]` | 55264 / 63455 | ② | FPGA 回显 |
| 🔥 `b_gear` | **按钮** | (262, 416, 66, 32) | `档位` | 2459 / 65535 | ② | 叠放在 t_gear 右端上层，档位下一循环（控件 12，⭐ 2026-10-31） |
| `t_lock` | 文本 | (340, 418, 134, 26) | `[推子: 实时生效]` | 38402 / 65523 | ① | 静态（黄底告警样式） |
| `t_lock_info` | 文本 | (32, 460, 454, 36) | `硬件锁状态: 实时响应` | 22477 / 63455 | ① | 静态 |

### 5. 卡片 D：多维调制生态区

| 控件名 | 类型 | 坐标 | 默认内容 | 前景/背景 | 字库 | 说明 |
|---|---|---|---|---|---|---|
| `l_card_d` | 文本 | (540, 290, 360, 20) | `MODULATION & HDMI / 调制与投屏生态` | 22477 / 透明 | ① | 静态 |
| `t_hdmi` | 文本 | (540, 320, 452, 44) | `HDMI: 实时示波器 (波形显示)` | 2459 / 63455 | ② | FPGA 回显（波形/李萨如/频谱三态） |
| `l_vp_title` | 文本 | (540, 374, 216, 16) | `音高颤音` | 22477 / 透明 | ① | 静态仓标题（左仓，⭐ 2026-10-31 双仓重排：仓标题移到静态标签，帧内只留量纲词） |
| `t_pd` | 文本 | (540, 394, 150, 22) | `深度 0%` | 9509 / 透明 | ② | FPGA 回显 `深度 NN%`（⭐ 2026-10-31 新文案） |
| `j_pd` | 进度条 | (540, 420, 216, 12) | val=0，🔴 **maxval=100** | 前景 2459 / 背景 — | — | FPGA 回显 `j_pd.val=`（音高颤音深度，与 t_pd 同源同值） |
| `t_pr` | 文本 | (540, 438, 150, 22) | `速率 1.0Hz` | 9509 / 透明 | ② | FPGA 回显 `速率 N.NHz`（⭐ 2026-10-31 新增，音高颤音速率，显示实际生效值） |
| `j_pr` | 进度条 | (540, 464, 216, 12) | val=0，🔴 **maxval=99** | 前景 2459 / 背景 — | — | FPGA 回显 `j_pr.val=`（音高颤音速率满量程百分比，与 t_pr 同源） |
| `l_vv_title` | 文本 | (770, 374, 216, 16) | `音量颤音` | 22477 / 透明 | ① | 静态仓标题（右仓，⭐ 2026-10-31 双仓重排） |
| `t_vd` | 文本 | (770, 394, 150, 22) | `深度 0%` | 9509 / 透明 | ② | FPGA 回显 `深度 NN%`（⭐ 2026-10-31 新文案） |
| `j_vd` | 进度条 | (770, 420, 216, 12) | val=0，🔴 **maxval=100** | 前景 55264 / 背景 — | — | FPGA 回显 `j_vd.val=`（音量颤音深度，与 t_vd 同源同值） |
| `t_vr` | 文本 | (770, 438, 150, 22) | `速率 5.2Hz` | 9509 / 透明 | ② | FPGA 回显 `速率 N.NHz`（⭐ 2026-10-31 新增，音量颤音速率，显示实际生效值） |
| `j_vr` | 进度条 | (770, 464, 216, 12) | val=2，🔴 **maxval=99** | 前景 55264 / 背景 — | — | FPGA 回显 `j_vr.val=`（音量颤音速率满量程百分比，与 t_vr 同源） |

> ⭐ **卡片 D 双仓重排（⭐ 2026-10-31 落地）**：废除 page0 原 `z_pd`/`z_vd` 两个仪表（页私有监视弧），
> 改为**左右双仓**「深度 + 速率」进度条组——每仓一个静态标题（l_vp_title/l_vv_title）+ 两个文本（深度/速率）
> + 两个进度条（j_pd/j_pr、j_vd/j_vr）。
> ⚠️ **page1 的 `z_pd`/`z_vd` 保留不动**（页私有，见 §八-1）：page0 的 j_pd/j_vd 是新增帧（ECH_F_JPD/JVD），
> ⛔ 不是改名——两页同名不同控件、互不干扰。
> ⭐ **速率口径**：t_pr 显示音高颤音**实际生效速率**（1.0~12.0Hz，来自推子档 1）；t_vr 显示音量颤音
> 相位增量换算速率（默认 5.2Hz）。进度条 j_pr/j_vr 是对应速率寄存器的**满量程百分比**（0..99）。
> ⚠️ **坐标待实物核对**（队友原《控件位置清单》为 800×480 名义，本屏 1024×600，此处坐标为建议值）。

### 6. 底部常驻状态条（y: 520..596）

| 控件名 | 类型 | 坐标 | 默认内容 | 前景/背景 | 字库 | 说明 |
|---|---|---|---|---|---|---|
| `t_dist_st` | 文本 | (64, 547, 110, 26) | `失真 [关]` | 22477 / 透明 | ② | FPGA 回显 |
| `t_chor_st` | 文本 | (224, 547, 110, 26) | `合唱 [开]` | 6822 / 透明 | ② | FPGA 回显 |
| `t_dly_st` | 文本 | (384, 547, 110, 26) | `延迟 [开]` | 55264 / 透明 | ② | FPGA 回显 |
| 🔴 `led_dist` | **双态按钮** | (36, 549, 20, 20) | sta=图片，pic=**0**(灰) / pic2=**1**(绿)，val=0 | — | — | ⭐ FPGA 回显 `led_dist.val=`（失真灯，§八-4） |
| 🔴 `led_chor` | **双态按钮** | (196, 549, 20, 20) | 同上，val=0 | — | — | ⭐ FPGA 回显 `led_chor.val=`（合唱灯） |
| 🔴 `led_dly` | **双态按钮** | (356, 549, 20, 20) | 同上，val=0 | — | — | ⭐ FPGA 回显 `led_dly.val=`（延迟灯） |
| `l_test` | 文本 | (510, 547, 44, 26) | `TEST` | 22477 / 透明 | ① | 静态小标 |
| `t1` | 文本 | (554, 547, 64, 26) | `关` | 22477 / 透明 | ② | 🔴 **FPGA 回显 `t1.txt`（关/4/8/16/32），必须有此控件** |
| `b_test` | **按钮** | (620, 545, 68, 28) | `切档` | 22477 / 65535 | ② | 触控 Test Mode 切档，事件见 §六 |
| `b_fx` | 按钮 | (704, 526, 292, 64) | `进入五级效果器拓扑链 ➔` | 65535 / 2459 | ② | 触控切页，事件见 §六 |

> ⭐ led_dist/led_chor/led_dly 状态圆点**已恢复并落地**（2026-10-29 RTL）：FPGA 随 fx_mask 联动回显
> `led_*.val=0/1`（与 t_dist_st/t_chor_st/t_dly_st 三状态条**同源**）。控件用双态按钮（同 p_hb 做法），
> 圆点图直接复用 `tools/hb_dots/`（pic=0 灰 / pic2=1 绿）；fx_mask 任一位变化 ⇒ 三灯 + 三状态条**共六帧齐发**。

---

## 四、Page 1：五级效果器拓扑链中枢

> **定位：全动态效果器链展板**（⭐ §八-3 已于 2026-10-29 RTL 落地）。FPGA 回显覆盖：八个 fx 仪表
> z_dg/z_dt/z_cl/z_mx/z_ll/z_lf/z_pr/z_vr（fx 寄存器直读**满量程百分比** 0..99）、十个数值文本 t_*_val
> （与同名仪表**同源同值**，格式 `NN%`）、cur（EC11 锁定参数）、gr（推子档短文本）、三个头部开关
> （0x19 翻转 ⇒ 六帧联动）。z_pd/z_vd 两页同名同源（§八-1）。
> ⭐ **page1 也要加后初始化事件** `printh 88 FF FF FF`（切页返回刷新 page1 动态字段，见 §六）。

### 1. 顶栏（y: 0..44）

| 控件名 | 类型 | 坐标 | 默认内容 | 前景/背景 | 字库 |
|---|---|---|---|---|---|
| `l_fx_title` | 文本 | (20, 10, 320, 24) | `FX PEDALBOARD TOPOLOGY CHAIN` | 9509 / 透明 | ① |
| `t_fx_route` | 文本 | (360, 10, 480, 24) | `IN ──► SERIAL AUDIO BUS (24-BIT/48K) ──► OUT` | 2459 / 透明 | ① |
| `t_fx_uart` | 文本 | (896, 9, 112, 26) | `UART 115.2K 8N1` | 6822 / 65523 | ① |

### 2. 五通道单块（x: 24..1000，每块宽 162，y: 62..514）

| 单块 | 头部按钮（触控） | 仪表×2 | 数值文本×2 | 底部说明 |
|---|---|---|---|---|
| 1 音高颤音 PITCH VIB | `b_pv_hdr` (24,62,162,106)：`printh 71 05 01 FF FF FF` | `z_pd`(63,198,84,84) ⭐活值 · `z_pr`(63,328,84,84) ⭐活值 | `t_pd_val`(63,284,84,24) `25%` · `t_pr_val`(63,414,84,24) `52%` | `t_pv_ft`(36,464,138,34) `硬件推子直通` |
| 2 高增益失真 DIST | `b_dist_hdr` (226,62,162,106)：⭐ `printh 71 19 01 FF FF FF` | `z_dg`(263,198,88,88) ⭐活值 · `z_dt`(265,328,84,84) ⭐活值 | `t_dg_val` `90%` · `t_dt_val` `45%` | `t_dist_ft`(238,464,138,34) `★ EC11 正在调节`（底 65523） |
| 3 立体声合唱 CHORUS | `b_chor_hdr` (430,62,162,106)：⭐ `printh 71 19 02 FF FF FF` | `z_cl`(469,198,84,84) ⭐活值 · `z_mx`(469,328,84,84) ⭐活值 | `t_cl_val` `63%` · `t_mx_val` `40%` | `t_chor_ft`(442,464,138,34) `两级共用干湿比` |
| 4 模拟磁带延迟 DELAY | `b_dly_hdr` (634,62,162,106)：⭐ `printh 71 19 04 FF FF FF` | `z_ll`(673,198,84,84) ⭐活值 · `z_lf`(673,328,84,84) ⭐活值 | `t_ll_val` `85%` · `t_lf_val` `55%` | `t_dly_ft`(646,464,138,34) `独立反馈回路` |
| 5 音量颤音 TREMOLO | `b_vv_hdr` (838,62,162,106)：`printh 71 05 02 FF FF FF` | `z_vd`(877,198,84,84) ⭐活值 · `z_vr`(877,328,84,84) ⭐活值 | `t_vd_val`(877,284,84,24) `60%` · `t_vr_val`(877,414,84,24) `38%` | `t_vv_ft`(850,464,138,34) `硬件推子直通` |

> ⭐ **0x19 翻转已落地（2026-10-29 RTL）**：`71 19 <bit>` = `fx_mask ^= bit`，屏**不用记账**，FPGA 翻转后回显
> **六帧**（t_dist_st/t_chor_st/t_dly_st 三状态条 + led_dist/led_chor/led_dly 三灯，见 §八-4）。⚠️ 翻转回显帧
> 只作用**当前页**——在 page1 按，回到 page0 时**后初始化事件的 `printh 88` 全量重发**会把新值刷上（见 §六，⭐ 已落地）。
> ⚠️ 所有仪表 **maxval=100**（⭐ 含 z_pr/z_vr——RTL 统一发满量程百分比 `ech_pct8(fx_rate_o)`，**不是 Hz 读数**）。
> ⭐ **仪表口径**：z_dg/z_dt=`ech_pct16h`、z_cl=`ech_pct11`、z_mx/z_lf/z_pr/z_vr=`ech_pct8`、z_ll=`ech_pct14`——
> 全部是对应 fx 寄存器（fx_gain/trim/chorlen/mix/fb/rate/dlylen_o）的**直读百分比**，t_*_val 文本与同名仪表同源同值。
> ⚠️ "点击设为 EC11 目标"：仪表触摸事件代码等 EC11 目标切换协议定稿后补（后续工作，非 §八-3）。

### 3. 底部（y: 532..592）

| 控件名 | 类型 | 坐标 | 默认内容 | 前景/背景 | 字库 |
|---|---|---|---|---|---|
| `cur` | 文本 | (24, 542, 340, 40) | `EC11: 增益 (0x11)` | 37134 / 65523 | ② |
| `gr` | 文本 | (378, 542, 350, 40) | `档 1 [音高颤音]` | 20781 / 64764 | ② |
| `b_back` | 按钮 | (742, 540, 258, 44) | `⬅ 返回演奏看板 (PAGE0)` | 65535 / 2056 | ② |

> ⭐ cur/gr **已动态**（2026-10-29 RTL）：cur 格式 `EC11: <参数名> (0x1N)`、gr 格式 `档 N [label]`（与 t_gear 同源）。
> ⭐ **cur 参数码口径**：N = par_sel 0..7 ↔ **0x11..0x18**，与 §六 串口变量表**完全线性对齐**
> （0x11 增益 / 0x12 补偿 / 0x13 混合 / 0x14 反馈 / 0x15 深度 / 0x16 速率 / 0x17 延迟长度 / 0x18 合唱长度）。
> ⚠️ 曾有 off-by-one（`'0'+par_sel` ⇒ 0x10..0x17）已修正，tb 判据按新口径复核通过（312 checks）。

---

## 五、颜色速查（RGB565 十进制，⭐ 上位机里填这个）

| 颜色 | Hex | RGB565 |
|---|---|---|
| 页面浅灰底 | #F0F3F6 | 63454 |
| 卡片白 / 浅填充 | #FFFFFF / #F6F8FA | 65535 / 63455 |
| 深炭黑正文 | #24292F | 9509 |
| 次级灰 | #57606A | 22477 |
| 电光蓝 | #0969DA | 2459 |
| 森林绿 | #1A7F37 | 6822 |
| 心跳绿 | #2DA44E | 2016 |
| 琥珀金 | #D97706 | 55264 |
| 警戒红 | #CF222E | 52517 |
| 黄底告警 | #FEF3C7 | 65523 |
| 深蓝黑（b_back 底） | #0F172A | 2056 |

> ⭐ 颜色列序实证为 **(前景 pco, 背景 bco)**：如按钮填 65535/2907 = 蓝底白字。

---

## 六、⭐⭐ 事件代码速查（逐个粘进对应事件页）

### ⭐⭐ 6.0-前 · 交互模型总则（先读这个，防走弯路）

> ⭐ 2026-10-30 补：很容易误以为"点按钮后要把所有变化写进按钮事件里"——**⛔ 不用**。
> 正确模型三句话：**屏只管发，FPGA 只管算，回显帧管显示**。

| 角色 | 职责 | 体现在哪 |
|---|---|---|
| **屏端事件** | 只写**一行 printh**：把手指动作翻译成一帧发给 FPGA 的报文 | §六各事件 |
| **FPGA** | 收帧 → 改内部状态 → **回发显示帧**：点名 objname 写控件属性（`.txt=` 文字 / `.val=` 数值 / `.bco=`/`.pco=` 颜色） | `uart_ui.v` 回显 FSM（56 非心跳帧） |
| **屏固件** | 收到回显帧 → **自动**改对应控件的显示。屏上没有任何"当前状态"变量 | 无需写代码 |

举例（点 b_timbre 切音色的完整闭环）：

```
点按钮 → 屏只发一帧 65 00 03（屏自己什么都不改）
→ FPGA 收到，切 timbre_sel_r，回发 t_timbre.txt="GUITAR"
→ 屏固件按 objname 找到控件、写 .txt 属性 → 大字自动从 BASS 变 GUITAR
```

⛔ **不要在按钮事件里写** `if(timbre==...) t_timbre.txt=...` 这类记账逻辑——状态源在 FPGA，
屏自己记账必然与 FPGA 失步。上位机里填的默认文字只是**上电初始值**，运行时由 FPGA 回显覆盖。

**仅有的三类屏端本地代码**（合法，与 FPGA 状态无关）：
1. **切页**：`page page1` / `page page0`
2. **心跳闪烁**：tm0/tm1 定时器翻圆点图（见下）
3. **后初始化**：切页回来发 `printh 88` 触发 FPGA 全量重发（见下）

**与队友 v2 定稿的有意差异（保留，均为已落地口径）**：
- **串口速率**：v2 写 500K → 本工程 **115200**（板载口 2026-10-28 改）
- **t_base**：v2 原案直接做成按钮 → v3 用**文本 + 叠放 b_oct 小按钮**（回显文字与按钮文案分离、互不覆盖）
- **page1 头部开关**：v2 写 TJC 原生自动帧（`65 01 02 01 …`）→ v3 用 **`71 19 <bit>` 翻转帧**（RTL 解析口径）

### 6.0 屏→FPGA 命令总表（⭐ 与 uart_ui.v rx 解析逐条对应）

| 命令 | HEX 帧 | FPGA 行为 | 状态 |
|---|---|---|---|
| 模式翻转 | `65 00 00` + 尾 | mode 翻转 + 回显 t_mode | ✅ 一直支持 |
| Test Mode 切档 | `65 00 02` + 尾 | 关→4→8→16→32→关 + 回显 t1 | ✅ 一直支持 |
| 🔥 音色循环 | `65 00 03` + 尾 | timbre_sel 0→1→2→3→0 + 回显 t_timbre + 下游（note_manager/looper/led#0）同步 | ✅ **2026-10-30 落地** |
| 🔥 滑音开/关 | `65 00 04` + 尾 | slide_en 翻转 + 回显 t_slide + 下游滑音链 | ✅ **2026-10-31 落地** |
| 🔥 鼓机节奏下一 | `65 00 05` + 尾 | drum 五态循环 `关→I→II→III→IV→关` + 回显 t_drum | ✅ **2026-10-31 落地**（五态） |
| 🔥 键盘打鼓开关 | `65 00 06` + 尾 | key_drum 翻转 + 回显 t_kd | ✅ **2026-10-31 落地** |
| 🔥 移调 +1 半音 | `65 00 07` + 尾 | trans_semi +1（fader_gear 内限 +12）+ 回显 t_trans | ✅ **2026-10-31 落地** |
| 🔥 移调 −1 半音 | `65 00 08` + 尾 | trans_semi −1（限 −12）+ 回显 t_trans | ✅ **2026-10-31 落地** |
| 🔥 循环录音 | `65 00 09` + 尾 | looper 录/停切换 + 回显 t_loop（四态配色） | ✅ **2026-10-31 落地** |
| 🔥 循环播放 | `65 00 0A` + 尾 | looper 播/停切换 + 回显 t_loop | ✅ **2026-10-31 落地** |
| 🔥 循环清空 | `65 00 0B` + 尾 | looper 清空该层 + 回显 t_loop | ✅ **2026-10-31 落地** |
| 🔥 推子档位下一 | `65 00 0C` + 尾 | 档位循环 + 回显 t_gear/cur/gr | ✅ **2026-10-31 落地** |
| 🔥 BPM +5 | `65 00 0D` + 尾 | BPM shadow +5（≤240）→ 小节线对齐生效 + 回显 t_bpm | ✅ **2026-10-31 落地** |
| 🔥 BPM −5 | `65 00 0E` + 尾 | BPM shadow −5（≥40）→ 同上 | ✅ **2026-10-31 落地** |
| ⭐ 实时上行开关 | `65 00 0F` + 尾 | uplink_sw 翻转 + 回显 b_uplink（`● 实时上行: 开启/关闭`） | ✅ **2026-10-31 落地** |
| 起始音（绝对） | `71 01 <val>` | val>>1 落 base_semi + 回显 t_base | ✅ 一直支持 |
| ⭐ 八度循环 | `71 1B 01` | base_semi 0→12→24→0 + 回显 t_base | ✅ **2026-10-29 落地** |
| 效果器掩码（绝对） | `71 10 <mask>` | fx_mask 直写 | ✅ 一直支持 |
| ⭐ 效果器翻转 | `71 19 <bit>` | fx_mask ^= bit + 回显**六帧**（三状态条 + 三灯） | ✅ **2026-10-29 落地** |
| 效果器参数 ×8 | `71 11..18 <val>` | 增益/补偿/mix/fb/depth/rate/延迟长/合唱长 | ✅ 一直支持 |
| 切档选择 | `71 05 <1/2>` | 推子档位（音高/音量颤音） | ✅ 一直支持 |
| ⭐ 全量重发 | `88` + 尾 | **56 帧全量回显**（非心跳帧，约 1286 字节，**每次都发**） | ✅ **2026-10-31 落地** |

> ⚠️ 帧尾 `FF FF FF` 为屏指令结束符，`printh` 里必须带上（下同）。⛔ 0x65 帧只认控件 ID **0..15**（其余静默丢弃）。
> ⭐⭐ **FPGA→屏回显帧型（5 种）**：`.txt="`（文本）/ `.val=`（数值）/ `.tim=`（心跳定时器）/ `.bco=`（背景色）/
> `.pco=`（前景色）——两种色帧为 §八-2 三态配色新增，色值 = RGB565 十进制原样 ASCII。

### 心跳闪烁（page0）

**tm0**（定时器，tim=500，en=1）事件：
```
if(p_hb.val==0)
{
  p_hb.val=1
}else
{
  p_hb.val=0
}
```

**tm1**（定时器，tim=1500，en=1）事件：
```
tm0.en=1
```

> 运行逻辑：FPGA 每秒发 `tm1.tim=1500` 持续复位 tm1 倒计时 ⇒ 联机时 tm1 永不超时；断联 ≤1.5s 后 tm1 超时 → `tm0.en=1` → 圆点闪。
> ⚠️ p_hb 是**双态按钮**（⛔ 不是图片控件，没有 `.pic` 属性）：sta=图片、pic=0/pic2=1，代码只翻 `.val`。

### ⭐ page0 / page1 后初始化事件（切页返回刷新，⭐ 两页都要加）

```
printh 88 FF FF FF
```

> **为什么要加**：切页期间 FPGA 发的本页更新帧会被屏丢弃（页私有）⇒ 返回显示旧值。
> 0x88 **每次收到都全量重发 56 帧**（2026-10-31 RTL）⇒ 每次回到该页自动拿最新全量
> （page1 的仪表 / 文本 / cur / gr 也一并刷新）。

### 基准音切八度（b_oct）

**b_oct** 弹起事件——⭐ **单命令版（本轮 RTL 0x1B 已落地，推荐）**：
```
printh 71 1B 01 FF FF FF
```

> FPGA 侧循环 0→12→24→0 并回显 t_base，屏**不用记账**。
> 备份（旧自记账版，无需 RTL 但硬件侧改动会记偏）：建全局变量 va_base，
> 0→`71 01 18`、12→`71 01 30`、24→`71 01 00`。

### 模式切换（b_mode）

**b_mode** 弹起事件（RTL 实锤：触摸 ID 0 = 模式翻转）：
```
printh 65 00 00 FF FF FF
```

### 🔥 音色循环（b_timbre 按钮 / h_timbre 热区，⭐ 2026-10-30 新增）

**b_timbre 按钮或 h_timbre 热区**弹起事件（RTL 实锤：触摸 ID 3 = 音色循环请求，两者发同一帧、RTL 无感知）：
```
printh 65 00 03 FF FF FF
```

> FPGA 侧 `timbre_sel_r` 循环 0=BASS→1=GUITAR→2=PIANO→3=PAD→0，与板载 S2 按键 /
> 调试串口 'I' **并联**；**点完后 t_timbre 大字由回显 FSM 自动同步刷新**（屏不用记账，tb 已验），
> 手弹音色（note_manager 兑底）、looper 录制音色、LED #0 同步变。

### Test Mode 切档（b_test）

**b_test** 弹起事件（RTL 实锤：触摸 ID 2）：
```
printh 65 00 02 FF FF FF
```

### 🔥🔥 page0 控制面板按钮组（⭐ 2026-10-31 新增 12 个）

**每个按钮弹起事件一行 printh**（RTL 实锤：控件 4..14，与调试串口同一条下游路径，
回显 FSM 自动刷新对应 t_* 文字，屏**不用记账**）：
```
b_slide：   printh 65 00 04 FF FF FF      // 滑音开/关（↔ 'W'）
b_drum：    printh 65 00 05 FF FF FF      // 节奏型下一（↔ 'D'）
b_kd：      printh 65 00 06 FF FF FF      // 键盘打鼓开/关（↔ 'K'）
b_tr_up：   printh 65 00 07 FF FF FF      // 移调 +1 半音（↔ 'F'）
b_tr_dn：   printh 65 00 08 FF FF FF      // 移调 −1 半音（↔ 'G'）
b_rec：     printh 65 00 09 FF FF FF      // 循环录音（↔ 'R'）
b_play：    printh 65 00 0A FF FF FF      // 循环播放（↔ 'L'）
b_clear：   printh 65 00 0B FF FF FF      // 循环清空（↔ 'C'）
b_gear：    printh 65 00 0C FF FF FF      // 推子档位下一（↔ 'J'）
b_bpm_up：  printh 65 00 0D FF FF FF      // BPM +5（40..240 饱和）
b_bpm_dn：  printh 65 00 0E FF FF FF      // BPM −5
b_uplink：  printh 65 00 0F FF FF FF      // 实时上行 开↔关（⭐ 2026-10-31，FPGA 回显 b_uplink 文本翻转）
```

> ⚠️ **BPM 两条的回显不是立即的**：`bpm_bar_quant` 对齐小节线后才写入 `play_seq`
> ⇒ ⭐ 最长等**一个小节**（120 BPM ⇒ 2 s）才看到 t_bpm 变——**不是按钮失灵**（与串口 'Q' 同行为）。
> ⚠️ **b_tr_up/b_tr_dn 连点**：fader_gear 内部限幅 ±12，到头后文字不变（正常）。
> ⭐ **t_vol/t_pedal 没有按钮**（见 §三 卡片 C 后的定位说明：音量无 FPGA 路径、踏板是物理输入）。

### 切页按钮

**b_fx** 弹起事件：`page page1`
**b_back** 弹起事件：`page page0`

### page1 五个头部按钮

```
b_pv_hdr：  printh 71 05 01 FF FF FF      // 切档 1（音高颤音）
b_vv_hdr：  printh 71 05 02 FF FF FF      // 切档 2（音量颤音）
b_dist_hdr：printh 71 19 01 FF FF FF      // ⭐ 翻转失真 Bit0
b_chor_hdr：printh 71 19 02 FF FF FF      // ⭐ 翻转合唱 Bit1
b_dly_hdr： printh 71 19 04 FF FF FF      // ⭐ 翻转延迟 Bit2
```

> ⭐ 0x19 三条**今天就能绑**（RTL 已落地）。翻转后 FPGA 回显三个状态条帧——在 page1 上发的帧
> 会被屏丢弃，但回 page0 时后初始化的 `printh 88` 会补上最新值。

---

## 七、⭐⭐ 字库字符集（⭐ 生成 6 份，每份粘同一行）

### 7.1 中文（一次全选复制）

```
演奏核心节奏循环无拍器物理外设监视调制与投生态指板模式变调音高颤量开关启闭基准最低原录音回放武装中空闲键盘打键位演奏主延踏板踩使能松推子控制档实示波波形显示李萨如图谱失真合硬件直通级共干湿比反馈路独立进五效果拓扑链点击切八度旋钮锁定增益补偿延迟时间长度模拟磁立体声返回看板深度速率正在调节锁状态响色滑鼓播上行
```

> ⭐ **2026-10-31 补末尾 4 字：色 滑 鼓 播** —— 🔴 按钮文字专用（切音色 / 滑音 / 打鼓 / ►播）。
> ⭐ **2026-10-31 再补 2 字：上 行** —— 🔴 b_uplink 帧文 `● 实时上行` 专用（⭐ 核验结论：原 153 字集中
> “上”“行”均不存在，须补入，否则 b_uplink 文本“上行”显示空白）。
> 🔴 **这是“按钮文字不显示”的头号根因**：按钮的文案和文本控件一样**走字库**，
> 字库生成时字符集里没这个字 ⇒ 屏上就是**空白**（中文）或方块（符号）。
> ⚠️ 按钮还要单独检查属性面板的 **font（字库）选了哪一档**（按钮统一选 ② 16px 那档）。

### 7.2 🔴 特殊符号（⛔ 不加必显示方块）

```
● ➔ ⬅ ★ ► ─ · ↕
```

> ⚠️ **按钮文案只用上表 + ASCII 里的字符**：`−1` 必须写成 ASCII `-1`（⛔ U+2212 不在集），
> `▶播` 必须写 `►播`（⛔ U+25B6 不在集，集里是 ► U+25BA）。

### 7.3 ASCII

字库工具勾选完整 ASCII（数字/字母/括号/百分号/冒号/方括号等全用到了）。

> ⭐ 生成步骤：工具 → 字库制作 → 编码 🔴 **UTF-8** → 字号选一档 → 粘贴 §7.1+§7.2 字符 → 生成。6 档字号各生成一次。
> ⚠️ 下载工程时**字库必须随工程一起下屏**，否则中文/符号全部方块。

---

## 八、⚠️ 已知边界与后续工作

### 1. z_pd / z_vd 两页重名（合法但要懂行为）

控件页私有，两页各有一个 `z_pd` 不冲突；但 FPGA 帧只作用于**当前显示页**的那个。page1 的 z_pd（深度旋钮）与 page0 的 z_pd（监视弧）是同一物理量，联机时在哪页哪页活。

### 2. t_loop 多态配色 ✅ 已落地（2026-10-29 RTL）

FPGA 加发 `t_loop.bco=` / `t_loop.pco=` 色帧（帧型新增），文案与配色**同源同发**（st_loop 变化 ⇒ 三帧齐挂起）：

| 状态 | 背景 bco | 前景 pco |
|---|---|---|
| 空闲 | 63455（浅灰） | 9509（深字） |
| 录音 | 52517（红） | 65535（反白） |
| 回放 | 6822（绿） | 65535（反白） |
| 武装 | 55264（琥珀） | 65535（反白） |

### 3. Page1 动态数据 ✅ 已落地（2026-10-29 RTL）

z_dg/z_dt/z_cl/z_mx/z_ll/z_lf/z_pr/z_vr + t_*_val + cur + gr 共 **25 字段全部有回显帧**（仪表与文本同源同值、
cur/gr 见 §四-3，帧型与口径见 §四-2 注）；tb 判据已扩充至 **312 checks PASS**。

### 4. led_* 状态灯 ✅ 已落地（2026-10-29 RTL）

`led_dist / led_chor / led_dly` 的 `.val=0/1` 随 fx_mask 联动（任一位变化 ⇒ 三灯 + 三状态条**共六帧齐发**）。
控件为双态按钮（圆点图复用 `tools/hb_dots/`），见 §三 底部状态条。

### 5. ⭐⭐ 卡片 B/D 重构 + 状态灯 + 实时上行开关 ✅ 已落地（2026-10-31 RTL）

| 项 | 落地内容 | 位置 |
|---|---|---|
| 鼓机五态 | t_drum 回显 `关` / `Pattern I/II/III/IV`（top.v `drum_on_r` 使能位 + `drum_pattern_r` 2 位计数，`关` = `src_b_valid` 里 `drm_evt_valid & drum_on_r` 闸门） | uart_ui.v ECH_F_DRUM / top.v L1098-1111 |
| t_kd 新文案 | `打鼓: 开启 [键位打鼓]` / `打鼓: 关闭 [音符演奏]` | uart_ui.v ECH_F_KD |
| 卡片 D 双仓 | 废除 page0 z_pd/z_vd 仪表，改 j_pd/j_vd/j_pr/j_vr 进度条 + t_pr/t_vr 文本 + l_vp_title/l_vv_title 静态仓标题 | uart_ui.v ECH_F_JPD/JVD/JPR/JVR/PRATE/VRATE |
| p_slide 状态灯 | 绿点 `.val=0/1`，与 t_slide 同源同发 | uart_ui.v ECH_F_PSLIDE |
| p_bpm 状态灯 | 橙点 `.val` 随节拍脉冲 `beat_i` 每拍翻转 0/1 | uart_ui.v ECH_F_PBEAT |
| b_uplink 实时上行 | 控件 15 翻转 `uplink_sw_o`，回显 `● 实时上行: 开启/关闭` | uart_ui.v ECH_F_UPL |

> ⭐ **p_bpm 橙点图**：`tools/gen_hb_dots.py` 已补橙色档（`p_bpm_on_amber.png`，RGB 217,119,6 ≈ 55264 琥珀金），
> 与 `p_bpm_off_gray.png` 成对使用；p_slide 复用现有灰/绿（`p_hb_on_green.png`/`p_hb_off_gray.png`）。
> ⭐ **b_uplink 的 FPGA 功能语义**：当前 `uplink_sw_o` 为空挂开关（top 只读消费，无下游动作），
> “实时上行”具体做什么**待队友裁定**；屏端已按“开↔关”按钮 + 回显文本落地。
> ⚠️ **卡片 D 双仓与 b_uplink 的坐标**为 1024×600 建议值（队友原清单 800×480 名义），**待实物核对**。

---

## 九、✅ 验收清单

### 模拟器（不接 FPGA）

| # | 操作 | 期望 |
|---|---|---|
| 1 | 编译 | ⭐ 0 错误（变量名无效 = 控件没建/名拼错） |
| 2 | 进 page0 | 心跳圆点 500ms 灰绿闪 |
| 3 | 点 b_fx / b_back | 两页互切；回 page0 触发全量刷新 |
| 4 | 中文/符号 | 无方块（方块 = 字库没下/字符没进集） |
| 5 | 模拟器串口窗口 | 点各按钮能看到 printh 的 HEX 输出 |

### 串口助手联调（USB-TTL 接屏，115200）

| # | 发什么（HEX） | 期望 |
|---|---|---|
| 1 | `00 FF FF FF` | 清缓冲（上电防杂波，官方 QA25） |
| 2 | `88 FF FF FF` | 🔴 **收到 56 帧全量回显**（约 1286 字节，非心跳帧）——最硬一条 |
| 3 | **再发一次** `88 FF FF FF` | ⭐ **又收到 56 帧**（重发已落地；旧 RTL 第二次只回心跳） |
| 4 | `71 19 01 FF FF FF` | ⭐ 失真**六帧**联动（三状态条 + 三灯；`失真 [关]`↔`[开]`、led_dist 0↔1） |
| 5 | `71 1B 01 FF FF FF` ×3 | ⭐ t_base 依次 C4→C5→C6→C4 循环 |
| 6 | 等 1s | 心跳帧 `tm1.tim=1500` 每秒一帧，圆点常闪不灭 |
| 7 | `71 11 <val> FF FF FF` | ⭐ 增益写 ⇒ page1 `z_dg.val=` + `t_dg_val.txt=` 同源两帧（值为满量程百分比） |
| 8 | `71 13 <val> FF FF FF` | ⭐ 混合写 ⇒ `z_mx.val=` + `t_mx_val.txt=`（混合=**0x13**，见 cur 码口径） |
| 9 | 🔥 `65 00 03 FF FF FF` ×4 | ⭐ 音色循环：t_timbre 依次 BASS→GUITAR→PIANO→PAD→BASS（⭐ 2026-10-30 落地） |
| 10 | 🔥 `65 00 04 FF FF FF` | ⭐ 滑音开/关：t_slide `开启↔关闭` 翻转 |
| 11 | 🔥 `65 00 05 FF FF FF` ×5 | ⭐ 鼓机五态循环：t_drum `Pattern I→II→III→IV→关→I` |
| 12 | 🔥 `65 00 07 FF FF FF` ×2 | ⭐ 移调：t_trans `0 SEMI`→`+1`→`+2` |
| 13 | 🔥 `65 00 08 FF FF FF` | ⭐ 移调回：t_trans `+2`→`+1` |
| 14 | 🔥 `65 00 09 / 0A / 0B` | ⭐ 循环三键：t_loop 四态文字+配色联动（录音中按 0B 回空闲） |
| 15 | 🔥 `65 00 0D FF FF FF` ×3 | ⭐ BPM：t_bpm 120→125→130→135（⚠️ 小节线对齐，最长等一小节） |
| 16 | 🔥 `65 00 0E FF FF FF` | ⭐ BPM 回落：135→130 |
| 17 | ⭐ `65 00 0F FF FF FF` | ⭐ 实时上行：b_uplink `● 实时上行: 开启↔关闭` 翻转 |
| 18 | ⭐ `65 00 06 FF FF FF` | ⭐ 键盘打鼓：t_kd `打鼓: 开启 [键位打鼓]`↔`关闭 [音符演奏]` 翻转 |

> ⚠️ 判据 2 若只收到部分帧：检查控件名是否与本清单逐字一致（t_base 不能叫 tBase）。
> ⚠️ 帧尾 `FF FF FF` 是屏的指令结束符，FPGA 自动处理；串口助手手动发时切 HEX 模式补发。
> ⭐ **上板前先跑仿真**：`tb/w3c/tb_uart_ui.sv` 回归 **392 checks PASS**（iverilog），覆盖 56 帧全量 burst、
> fxmask 六帧联动、t_loop 多态配色、page1 25 字段、cur 码 0x11..0x18 口径、b_timbre 音色闭环、
> 控件 4..15 面板脉冲独热+严格单拍、鼓机五态循环、卡片 D 双仓、p_slide/p_bpm 状态灯、b_uplink 翻转、
> 未知控件/bit7 别名负判据等。

---

## 十、⭐ 终稿规格速查表对齐核对（2026-10-30）

> 对照《三、串口屏终稿规格速查表（供测试与联调对齐）》逐字段做代码级核对。
> 🔴 **红线**：电子节拍器（Metronome）与削波告警（Audio Clip）已裁定**彻底废除**，工程中**未新增**任何相关屏控件/字段（`fx_dist_clip_cnt_o` 等 RTL 存量另议）。

### 15 组字段核对矩阵（page0）

| # | 字段 | 终稿要求 | RTL 现状 | 结论 |
|---|---|---|---|---|
| 1 | t_timbre | BASS/GUITAR/PIANO/PAD 循环 | 四态循环，b_timbre 闭环 + 点后大字由回显帧自动同步 | ✅ 对齐 |
| 2 | t_mode | 指板 ⇄ 钢琴 | `指板模式/钢琴模式` 二态，b_mode 闭环 | ✅ 对齐 |
| 3 | t_base | C4/C5/C6 循环 | b_oct 三档循环（验收判据 5） | ✅ 对齐 |
| 4 | t_trans | -12 ~ +12 半音 | 符号+数值（`+1 SEMI` 等） | ✅ 对齐 |
| 5 | t_slide | 开/关 | `开启/关闭` 翻转 | ✅ 对齐 |
| 6 | t_bpm | 40~240 大字号 | BPM 数值帧 + shadow 对齐 | ✅ 对齐 |
| 7 | t_loop 空闲态 | `空闲` | 一致 | ✅ 对齐 |
| 8 | t_loop 回放态 | `▶ 循环回放中 PLAY` | 🔥 2026-10-30 已修：`●`→`►`（U+25BA；⛔ 不用 ▶ U+25B6，§7.2 字库集里是 ►） | ✅ 已修 |
| 9 | t_kd | 键盘打鼓状态 | 一致 | ✅ 对齐 |
| 10 | t_vol | 主音量监视 | 一致（屏控增益化另议） | ✅ 对齐 |
| 11 | t_pedal | 延音踏板 | 一致 | ✅ 对齐 |
| 12 | t_hdmi | 实时示波器/李萨如/彩虹FFT | 三态一致 | ✅ 对齐 |
| 13 | t_pd / t_vd | 外设监视弧 | 一致（页私有见 §八-1） | ✅ 对齐 |
| 14 | 底部三灯 + b_fx | led_dist/chor/dly + 跳转 | fx_mask 六帧联动（§八-4） | ✅ 对齐 |
| 15 | t_drum / t_gear / t_lock | 见下三项 | — | ⚠️ **1 处待裁定**（t_drum 已修，见下） |

### ⚠️ 结构性差异（待用户/队友裁定）

| 字段 | 终稿写法 | RTL 现状（证据） | 差异与建议 |
|---|---|---|---|
| ~~t_drum~~ | ~~`关 / 开 I / II / III / IV` 五态~~ | ✅ **已修（2026-10-31）**：top.v `drum_on_r` 使能位 + `drum_pattern_r` 2 位计数，五态循环 `关→I→II→III→IV→关`（`关` = `src_b_valid` 里 `drm_evt_valid & drum_on_r` 闸门） | ✅ 已对齐，无需再改 |
| t_gear | `档0变调/档1音高颤音/档2音量颤音`（0 基） | 显示 `st_gear_c+1`（档1变调/档2音高颤音/档3音量颤音，**1 基**） | 二选一：RTL 改 0 基（去掉 +1）或终稿改 1 基；**1 基更符合日常读法，建议改终稿** |
| t_lock | `实时/锁定` | **屏端静态文本**，FPGA 无对应信号（推子锁在屏侧） | 若要 FPGA 驱动需新增锁状态通路；**现状屏自治即可，建议保持** |

---

## 附 · 关联

| 想看什么 | 去哪 |
|---|---|
| ⭐ FPGA 回显实现（57 字段全动态 + 心跳 + 三件套 + 音色按钮闭环 + page0 面板 12 按钮 + 卡片 B/D 重构 + 状态灯） | `rtl/w3c/uart_ui.v` · tb：`tb/w3c/tb_uart_ui.sv`（392 checks） |
| ⭐ 心跳圆点 PNG 生成脚本 | `tools/gen_hb_dots.py` → `tools/hb_dots/` |
| ⭐ 改档记录（500k→115200） | `rtl/top.v` :1243-1250 |
| 修正过程存档（12 处 v2 错误对照） | `hmi7/串口屏v2-修订版-20261029.md` |
| 旧 2 寸屏（ESP32 侧）文档 | `esp32/串口屏控件清单.md` 等（⛔ 与本屏无关，别混用） |
