hokuu1102/Gowin2026-PolySynth/bringup/28-上板测试清单-J9接线与效果器-20261015.md

# 上板测试清单 —— `J9` 接线 ＋ 效果器触发（2026-10-15）

> ⭐ **本文回答两件事**：**怎么接、怎么测**（含这次的 `J10` 教训）＋ **效果器怎么触发**。
> ⭐ **位流**：`impl/pnr/Gowin2026.fs`（＝ `evidence/fx_splitcone_20261015/Gowin2026_splitcone_61.1MHz.fs`）
> **sha256**：`5F07A2048FA0821E00C2CD29B1B3F951B7C8BB2B80327E765164E883BF3B0914` · 19.8 MB · 2026-10-15 21:07:35
> **时序**：⭐ **0 setup / 0 hold** · `Fmax 61.067 MHz`（约束 50 MHz ⇒ 余量 **+22%**）· CLS 88% · BSRAM 103/118

---

## 〇、⭐ 这次踩的坑：**插到 `J10` 上去了**

```
ADC（N1~N8）＋ 按键灯链（N17~N24）＋ 调试串口（N25/N26）—— ⭐ 三样全在【同一个 J9】上
⇒ ⭐ 插到 J10 ⇒ 三样【同时】死 ⇒ 症状就是"左右手板都没反应 + 灯不亮 + 串口没反应 + 心跳快闪"
📌 教训：⭐ 三个症状同时出现时，先怀疑【它们共用的那个连接器】，⛔ 别一根一根查信号线
```

---

## 一、⭐ 接线（`J9` 逐针 —— 2×20 / 40 针，2.54 mm）

| 针 | 信号 | FPGA ball | 用途 |
|---|---|---|---|
| **N1** | `spi_sclk` | E14 | ⭐ **两片 ADC 共用** |
| **N2** | `spi_mosi` | E13 | ⭐ **两片 ADC 共用** |
| **N3** | `spi_miso[0]` | C15 | 左手板 1 |
| **N4** | `spi_cs_n[0]` | C14 | 左手板 1 |
| **N5** | `spi_miso[1]` | B13 | 左手板 2 |
| **N6** | `spi_cs_n[1]` | C13 | 左手板 2 |
| ⭐ **N7** | `spi_miso[2]` | A14 | ⭐ **右手板**（⚠️ 旧排查清单漏了这两针） |
| ⭐ **N8** | `spi_cs_n[2]` | A13 | ⭐ **右手板** |
| ⭐ **N11** | **`+5V`** | — | ⭐ **拓展板的电** |
| ⭐ **N12** | **`GND`** | — | ⭐ **地** |
| **N17** | `led_le` | A21 | 按键灯链（锁存） |
| **N18** | `led_sdi` | B21 | 按键灯链（数据） |
| **N19** | `led_clk` | B18 | 按键灯链（时钟） |
| **N20** | `led_oe_n[0]` | B17 | 左手板 1 位选 |
| **N21** | `led_oe_n[1]` | C17 | 左手板 2 位选 |
| ⭐ **N25** | `uart_tx` | D15 | → **USB-TTL 的 RX** |
| ⭐ **N26** | `uart_rx` | D14 | ← **USB-TTL 的 TX** |

**USB-TTL**：⭐ **必须交叉**（`N25`→助手 RX · `N26`←助手 TX）· ⭐ **必须共地** · ⭐ **500000 8N1**
⚠️ **`N11`(+5V)/`N12`(GND) 夹在信号针中间** ⇒ ⭐ **插偏一个针就可能把 5V 灌到信号脚上**（会打坏 IO）⇒ 插之前数一遍针位。

---

## 二、上电三看（⭐ 不用仪器）

| # | 看什么 | ✅ 正常 |
|---|---|---|
| 1 | **心跳灯**（V13，板载绿） | ⭐ **慢闪 ≈1 Hz**（0.5 s 翻转） |
| 2 | **开机自检和弦** | ⭐ 复位后自动响 **A4+C#5+E5** 约 **1 秒** ⇒ **证明音频链活着** |
| 3 | 心跳灯**是否快闪** | ⚠️ **快闪 = 有故障被锁存**（⭐ 按一下复位再看：<br>**立刻又闪** = 开机就错；**先慢闪过一会才闪** = 运行中出错；**一直慢闪** = 上次的残留） |

---

## 三、串口通不通（⭐ 用 `'P'`，⛔ 别用 `'T'`）

```
发 'P'（HEX 50）  ⇒ 应回 Q<轴号><dpos>
```
| 命令 | 作用 | 回包？ |
|---|---|---|
| `'T'` | 逐轴 tare（重新记零点） | ⛔ **不回**（纯动作，⚠️ 用它测串口是无效测试） |
| **`'P'`** | 读 `pos` | ✅ 回 `Q<轴号><dpos>` |
| `'V'` | 读 span 状态 | ✅ 回 |

⭐ **判据**：`'P'` **有回包但 pos 全 0** ⇒ 串口活、ADC 死 ⇒ 查 `N1~N8`。
⭐ **`'P'` 什么都不回** ⇒ 串口本身不通 ⇒ 查 **共地 / 交叉 / 波特率 500000**。

---

## 四、按键通不通

| 测 | ✅ 正常 |
|---|---|
| 按一个键 | 出声 ＋ 对应**键灯亮** |
| 没反应 | 查 `J9 N1~N8`（⭐ 左右都坏 ⇒ 查共用的 `N1/N2`；只坏一边 ⇒ 查那侧的 `miso/cs_n`） |

---

## 五、⭐⭐ 效果器怎么触发

### 5.1 帧格式（⭐ 与串口屏同一套协议）

```
71 <变量序号> <值> FF FF FF          （HEX，500000 8N1）
```

### 5.2 变量表

| 序号 | 名字 | 值域 | 换算 | 上电默认 |
|---|---|---|---|---|
| `0x10` | **mask** | 0..254 | 直传（位掩码） | `0`（全关） |
| `0x11` | **gain** | 0..254 | ×256 ⇒ Q4.12（**32⇒2.0** · 64⇒4.0 · 254⇒15.875） | `64`（4.0） |
| `0x12` | **trim** | 0..254 | ×256 ⇒ Q1.15（32⇒0.25） | `32` |
| `0x13` | **mix** | 0..254 | Q0.8（0=全干 255≈全湿） | `128` |
| `0x14` | **fb** | 0..254 | Q0.8（延迟反馈） | `96` |
| `0x15` | **depth** | 0..254 | 直传（⭐ **0 = 数值恒等**） | `0` |
| `0x16` | **rate** | 0..254 | 直传（颤音速率） | `7` |
| `0x17` | **dlylen** | 0..254 | ×128 采样（64⇒8192⇒168 ms；⭐ **>127 饱和到 16383**） | `64` |
| `0x18` | **chorlen** | 0..254 | ×32 采样（23⇒736⇒15 ms；⭐ **>63 饱和到 2047**） | `732` |

### 5.3 掩码速查（⭐ 已修正）

```
0x00 全关        0x01 只失真        0x02 只合唱        0x04 只延迟
0x07 = 失真+合唱+延迟（⭐ 这才是"全开"）
```
🔴 **`bit4` 是【空闲位】**（`fx_chain.v:168-173` 明写"bit4 空闲"）⇒
⭐ **`0x17` 与 `0x07` 完全等价**，⛔ **别指望它开颤音**（旧文档写"0x17 全开（含颤音）"是**错的**，已更正）。

### 5.4 ⭐⭐ 颤音怎么开（最容易搞错的一条）

**颤音级【常开】**，它**没有使能位** —— 只由 **`depth`** 控制：
```
71 15 60 FF FF FF     ⭐ depth = 96 ⇒ 音量周期起伏（这才是"开颤音"）
71 15 00 FF FF FF     关掉（depth=0 ⇒ 数值恒等，听不出）
```
📌 `rate`（`0x16`）控制速率，默认 7。

### 5.5 用工具（推荐）

```bash
python tools/fx_ctrl.py --port COMxx list        # 看变量表（⚠️ 是【本地默认值】，本协议无读回通路）
python tools/fx_ctrl.py --port COMxx on          # 发 0x17（= 0x07 等效）
python tools/fx_ctrl.py --port COMxx off         # 全关
python tools/fx_ctrl.py --port COMxx mask 0x01   # 只失真
python tools/fx_ctrl.py --port COMxx mask 0x04   # 只延迟
python tools/fx_ctrl.py --port COMxx gain 64     # 失真 4.0 倍（默认档）
python tools/fx_ctrl.py --port COMxx drive 64    # ⭐ 归一化驱动（gain 64 + trim 32，推力↑音量不变）
python tools/fx_ctrl.py --port COMxx depth 96    # ⭐ 开颤音
python tools/fx_ctrl.py --port COMxx sweep       # ⭐ 增益扫描（32→240，找"破"的点）
python tools/fx_ctrl.py --port COMxx raw 10 07   # ⭐ 发任意帧体（⛔ 不带返回码 0x71）
```
⚠️ **`raw` 的示例已修正**：原来写 `raw 71 10 17` ⇒ 实际会发 `71 71 10 17 FF FF FF`（**多发一个 `0x71`**）⇒ `body_q = 0x71` 不匹配任何变量 ⇒ **静默无效**。⭐ 现在是 **`raw 10 07`**。

### 5.6 串口助手手动发（HEX 模式，⭐ 直接抄）

```
71 10 01 FF FF FF     只失真（应该明显"破"）
71 10 02 FF FF FF     只合唱（应该变宽）
71 10 04 FF FF FF     只延迟（应该有回声）
71 10 07 FF FF FF     ⭐ 全开（失真+合唱+延迟）
71 11 40 FF FF FF     失真增益 64 ⇒ 4.0 倍（⭐ 默认档）
71 11 FE FF FF FF     失真增益 254 ⇒ 15.875 倍（最大可发）
71 12 20 FF FF FF     失真补偿 32 ⇒ 0.25（⭐ 默认档）
71 13 80 FF FF FF     延迟混合 128
71 14 60 FF FF FF     延迟反馈 96
71 15 60 FF FF FF     ⭐ 颤音深度 96（⭐ 这才是"开颤音"）
71 17 C8 FF FF FF     ⭐ 延迟长度 200 ⇒ 饱和到 16383（最长回声；⭐ 已修，以前会变成 41 µs）
71 10 00 FF FF FF     全关
```

---

## 六、⭐ 上板验收步骤（按顺序）

```
1. ⭐ 烧完先别发任何帧 ⇒ 听起来应该和"没有效果器"【一样】（零回归）
      📌 代价：整体延迟 19 拍 = 380 ns（相对音频周期 20.5 µs 是 1.9%，听不出来）
2. 发 71 10 07 FF FF FF ⇒ ⭐ 灯 7 应该亮（⚠️ 颜色别信，见 §七）
3. 按住一个音，逐个试：
      71 10 01 ⇒ 只失真（"破"）
      71 10 02 ⇒ 只合唱（变宽）
      71 10 04 ⇒ 只延迟（回声）
4. ⭐ 失真"听不出来" ⇒ 扫增益：sweep，或手发 71 11 20 / 40 / 60 / 80 / A0 / C0 / E0 / FE
      （失真够不够 = 增益能不能把信号推过满量程）
5. ⭐ 颤音：71 15 60 FF FF FF ⇒ 音量应周期起伏；71 15 00 关掉
6. ⭐ 延迟拉到最长：71 17 C8 FF FF FF ⇒ 现在真的到 16383 采样
7. 回干声：71 10 00 FF FF FF ＋ 71 15 00 FF FF FF
```

---

## 七、⚠️ 四个必须知道的坑

| # | 坑 | 说明 |
|---|---|---|
| **1** | **值 `0xFF` 不可用** | 它是**帧尾标记**（`FF FF FF`）⇒ 所有变量**最大只能发 254**。⭐ 掩码只用 bit0/1/2 ⇒ 最大 `0x07`，⛔ 永远不需要 0xFF（工具会**主动拒绝** 0xFF） |
| **2** | **值只有一个字节** | 所以增益只能表达 **256 的整数倍**（32/64/254…）。要精确写 Q4.12 原值用 `gain-raw` |
| **3** | ⚠️ **灯 7 的颜色【不可信】** | 审查发现（`P1-6`）：`ui_fx_sel = ui_fx_mask[1:0]` 把**位掩码当枚举下标**用了 ⇒ `0x01`(只失真) 显示成"合唱"色、`0x07` 显示成"混响"色（根本不存在的效果）；而且 `0x08/0x20/0x40/0x80` 会让灯亮却**零效果**。<br>⇒ ⭐ **只用"亮/灭"判断有没有开效果器，⛔ 别信颜色**（这是**未修**的已知缺陷） |
| **4** | **链延迟 = 19 拍**（⭐ 不是旧文档写的 17 拍） | 拆时序锥后 `fx_delay` 4→5 级，链上有**两个**实例 ⇒ 17→**19** 拍（380 ns）。⭐ 听不出来，但**零回归口径要按 19 拍写** |

---

## 八、本次交付相对上一版的改动（⭐ 烧之前值得知道）

| 改动 | 内容 |
|---|---|
| 🔴 **P0-1 修** | `dlylen > 127` / `chorlen > 63` 的"饱和值"原来写成 `14'd16384`/`11'd2048` ⇒ ⭐ **字面量被截断成 0** ⇒ 延迟被夹到 **2 样点（41 µs）**。✅ 现在饱和到 **16383 / 2047** |
| 🟠 **P1-18 修** | 合唱在 `基础延迟 < 128` 时**读地址绕过写指针** ⇒ 有效延迟每 0.67 s 跳 ~39 ms。✅ 现在按模式夹取下界 |
| 🔴 **时序修** | 合唱锥一拍里塞了 2 个乘法 ＋ 2 组饱和 ＋ RAM 写口（**21.028 ns / 20 ns**）⇒ 拆成两级 ⇒ ⭐ **Fmax 40.9 → 61.067 MHz**，setup 违例 **133 → 0** |
| ⚙️ **构建配置修** | `impl/Gowin2026_process_config.json` 里的 `place_option` 被改成 **2（时序优先）** ⇒ ⭐ **676 根不布通**。✅ 改回默认 **0** ⇒ 15m30s 布通 |
| 📝 文档/工具 | 掩码表去掉 `bit4=颤音`；`254⇒7.94`（原写 7.97）；`raw` 示例改 `10 07`；饱和值写成 16383/2047 |
| ⭐ **gain/trim 映射 ×128 ⇒ ×256** | 字节→Q 映射各多补一个零（**恰好占满 16 位**）⇒ 上限 `254⇒15.875`（原 7.94）。⭐ **默认档字节变为 `gain=64` / `trim=32`**（语义不变：净增益仍是 4.0×0.25=1.0）；⭐ 复现复位默认请发 **(64, 32)**。⭐ 工具新增 `drive <值>`（归一化驱动，推力↑音量不变） |

---

## 九、⛔ 本次**未修**的已知项（⛔ 别当成"已解决"）

```
· 灯 7 颜色映射（P1-6，见 §七-3）
· evt_upstream 的 timbre 没随事件入队（P1-13）—— 影响 ESP32 转 MIDI 的乐器号
· 18 根可观测线在顶层悬空（P1-14 等）—— 上板看不到"参数被夹/被丢"
· 判据侧的多个空洞（P0-3/`err_cnt`/`mask=0` 从未被激励 …）
· 完整清单：review/效果器运行时-肌肉集团审查-20261015.md（5 P0 / 18 P1 / 39 P2 / 32 P3）
```
