hokuu1102/Gowin2026-PolySynth/esp32/串口屏控件清单.md

# 🎛️ 串口屏控件清单（照这个在上位机里拖）

> **屏型号**：⭐ **`TJC3224T120_011R_A01`**（淘晶驰 T1 系列，2.0 寸，电阻触摸，**320×240**）
> **用途**：实时显示 ESP32 通路的「传输进度 / 曲谱名 / 状态 / 蓝牙连接」
> **上位机**：USART HMI 1.68.1 —— ⭐ **安装包已下载并解压**（⚠️ 放在 esp32 目录下的 _downloads 子目录，⛔ 该目录已 gitignore、不入库）
> **关联**：`esp32/ble/README.md` · `esp32/串口屏上位机使用说明.md` · ⭐ **`esp32/串口屏指令表.md`（可直接粘贴的调试指令）** · `files/20-代码/ESP32通路总体架构-20260922.md`

---

## 一、⭐ 建工程（第一步）

| 项 | ⭐ 填什么 |
|---|---|
| **设备型号** | ⭐ **`TJC3224T120_011R_A01`**（⚠️ 必须选对，否则分辨率/触摸不对） |
| **方向** | ⭐ **横屏 320 × 240**（⚠️ 官方规格是 **320×240**，⛔ 不是 240×320） |
| ⭐⭐ **工程编码** | ⭐⭐ **`UTF-8`**（🔴 **必须**，见下） |
| **波特率** | ⭐ **115200**（⭐ 与固件 `BLE_HMI_BAUD` 一致） |
| **页面** | 用默认的 **`page 0`** 即可，⛔ 不用加新页 |

> 🔴 **工程编码必须选 `UTF-8`，⛔ 不是 GB2312 / ascii / GBK**。
> ⭐ 理由：**ESP32 固件源码里的中文就是 UTF-8**，两边必须一致
> （官方 QA121：传输汉字要保证两边编码一致）。
> ⚠️ **选 GB2312 ⇒ 屏上中文变乱码。**
> 🔴 而且**编码不能事后改**（官方 QA86：改了会乱码、要手工重输）。
> ⭐ **字库编码也必须同样选 UTF-8**（官方 QA27：工程与字库编码必须一致）。

> ⚠️ **波特率必须两边一致** —— 屏里设 `bauds`，固件里设 `BLE_HMI_BAUD`。

---

## 二、⭐⭐ 控件清单（7 个，按下表逐个拖）

> ⭐ **`ID` 必须严格按表填** —— 固件是按这些 ID 拼命令的（`g0.txt=`、`j0.val=` 等），
> ⛔ 名字不一样就收不到。

### 2.1 ⭐⭐ 48 号字排版（⭐ 占满 320×240）

⭐ **目标**：字尽量大 + **版面用满**（上下左右各留 **4 px**）。

| # | **ID** | **类型** | **X** | **Y** | **宽** | **高** | **初值** | ⭐ **字号** | 说明 |
|---|---|---|---|---|---|---|---|---|---|
| **1** | ⭐ **`t0`** | 文本 | **4** | **4** | **76** | **56** | `曲谱：` | ⭐ **24** | ⭐ **固定标签**（⛔ 固件不改它） |
| **2** | ⭐ **`g0`** | ⭐ **滚动文本** | **84** | **4** | **232** | **56** | `----` | ⭐⭐ **48** | ⭐ **曲谱名**（长名靠滚动） |
| **3** | ⭐ **`j0`** | **进度条** | **4** | **64** | **232** | **56** | `val = 0` | — | ⭐ 传输进度 |
| **4** | ⭐ **`n0`** | **数字** | **240** | **64** | **76** | **56** | `val = 0` | ⭐ **48** | ⭐ 百分比数字 |
| **5** | ⭐ **`t1`** | 文本 | **4** | **124** | **312** | **56** | `待机` | ⭐⭐ **48** | ⭐ **状态字**（⛔ 无前缀） |
| **6** | ⭐ **`t2`** | 文本 | **4** | **184** | **196** | **52** | `0/0` | ⭐ **32** | 事件计数（⛔ 无前缀） |
| **7** | ⭐ **`t3`** | 文本 | **204** | **184** | **112** | **52** | `BT --` | ⭐ **32** | ⭐ **蓝牙**（⭐ 独立 ⇒ 能单独变色） |

### 2.2 版面示意（320×240 横屏）

```
┌──────────────────────────────────────────────┐ 0
│ 曲谱： 09_Conjurer_Theme                     │ t0(4,4,76×56, 24号)
│                                              │ g0(84,4,232×56, 48号)
├──────────────────────────────────────────────┤ 60
│ [██████████████░░░░░░░░]           45        │ j0(4,64,232×56)
│                                              │ n0(240,64,76×56, 48号)
├──────────────────────────────────────────────┤ 120
│ 播放中                                        │ t1(4,124,312×56, 48号)
├──────────────────────────────────────────────┤ 180
│ 4820/11865                    BT OK          │ t2(4,184,196×52, 32号)
│                                              │ t3(204,184,112×52, 32号)
└──────────────────────────────────────────────┘ 240
```

⭐ **四行从 Y=4 排到 Y=236** ⇒ ⭐ **几乎占满**。

### 2.3 ⭐⭐ 尺寸是怎么算出来的（⭐ 不是拍脑袋）

⭐ **48 号字的实际尺寸**：

| 项 | 值 |
|---|---|
| 单个**中文** | **48 px** 宽 |
| 单个 **ASCII** | **24 px** 宽 |
| **行高** | ⚠️ 约 **56 px**（⚠️ 待上机核实，见 §2.5） |

⭐ **逐行算**（可用宽度 = 320 − 4×2 = **312 px**）：

| 行 | 算式 |
|---|---|
| **第 1 行** | `t0` 3 个中文 @**24**号 = 72 + 4 内边距 = **76** ⇒ `g0` = 312 − 76 = **232** |
| **第 2 行** | `n0` "100" 3 个 ASCII @48 = 72 + 4 = **76** ⇒ `j0` = 312 − 76 = **232** |
| **第 3 行** | `t1` 整宽 = **312** |
| **第 4 行** | 🔴 **放不下全 48 号** ⇒ 见 §2.4 |

### 2.4 🔴 第 4 行为什么用 **32 号**（⭐ 一个真实的取舍）

⭐ **48 号下算不过账**：

```
t2 "4820/11865" = 10 个 ASCII × 24 px = 240 px
t3 "BT OK"      =  5 个 ASCII × 24 px = 120 px
                          合计 = 360 px  >  312 px 可用
                          🔴 超 48 px ⇒ 放不下
```

⭐ **三个方案**：

| 方案 | 做法 | 取舍 |
|---|---|---|
| **A（⭐ 本清单采用）** | `t2`/`t3` 用 **32 号** | ⭐ **保持两栏并列**，仅字号降一档 |
| **B** | `t2` 只显示已发条数（`4820`） | ⚠️ **丢了总数** |
| **C** | 两行合并成一行 `4820/11865 BT OK` @32 | ⚠️ 少一行，但更宽松 |

> ⭐ **32 号下**：`t2` = 10 × 16 = 160 px，`t3` = 5 × 16 = 80 px，合计 **240 < 312** ✅ 放得下。

### 2.5 ⚠️ 上机后必须核实的三件事

| # | 核实什么 | ⚠️ 不对的后果 |
|---|---|---|
| **1** | ⭐ **48 号字库能不能生成** | 🔴 **不成立则整套坐标要重算** |
| **2** | ⭐ **实际行高**（我按 **56 px** 算） | ⚠️ 若实际是 52 或 60 ⇒ **行之间会缝/会叠** |
| **3** | ⚠️ **`j0` 的 `maxval` 是不是 `100`** | ⚠️ 否则**进度条比例不对** |

> ⚠️ 若行高不是 56，⭐ **告诉我实际值，我按比例重算全部坐标**。

### 2.6 ⭐⭐ 相比更早的版本，砍掉了什么

| 砍掉的前缀 | 为什么能砍 |
|---|---|
| ⛔ `状态：` | ⭐ 那行**只有状态字**，不会有歧义 |
| ⛔ `事件：` | ⭐ 格式 `4820/11865` 自明 |
| ⛔ `蓝牙：` | ⭐ 用 **`BT`** 2 个 ASCII 字符代替 |
| ⛔ `缓冲：` | ⚠️ **整个控件都去掉了**（320×240 排不下） |
| ⛔ `%` | ⭐ **旁边就是进度条**，不会误解 |

⭐ **只保留 `曲谱：`** —— ⚠️ 否则**分不清哪行是歌名**（尤其 `09_Conjurer` 这种）。

### ⭐⭐ 为什么 `t3`（蓝牙）要独立成控件

🔴 **关键**：固件要用 **`t3.pco`** 给它**变色**（已连接=绿、未连接=红），
⚠️ 而 **`pco` 是【整个控件】的字体色** ⇒
🔴 **若把蓝牙和事件数合并成一个控件，数字会跟着一起变红/变绿。**

⭐ 而**不推荐用 `✓` / `✗` 勾叉**：
⚠️ 它们是 **Unicode 符号（U+2713/U+2717）**，**字库里多半没有** ⇒ 显示成方块；
⭐ **`BT OK` / `BT --` 是 ASCII，字库必有** ⇒ 零风险。

### ⭐ `g0`（滚动文本）必须设的属性

| 属性 | ⭐ 设什么 | 为什么 |
|---|---|---|
| 🔴 **`txt_maxl`** | ⭐ **60**（给够） | 🔴 官方：**"可通过上位机修改，⛔ 不可通过指令修改"** ⇒ ⚠️ **填小事后改不了** |
| **`dir`** | **1**（从右往左） | ⭐ 歌名常用方向 |
| **`tim`** | **500** | ⚠️ 太小会晃眼（最小 80） |
| **`dis`** | **4** | 滚动幅度（2~50） |
| **`en`** | **1**（开启） | — |
| 🔴 **`isbr`** | **0**（不换行） | 🔴 官方警告：**"滚动文本不建议换行显示，会导致显示效果有问题"** |

> ⚠️ **为什么用滚动文本**：⭐ **48 号字下**每个 ASCII 占 **24 px** ⇒
> ⚠️ 歌名可视区只有 **232 px** ⇒ **只能放约 9 个 ASCII 字符**
> ⇒ 🔴 **长歌名必然截断**。⭐ **滚动文本不限长度。**

> ⚠️ **为什么 `n0` 是「数字」控件而不是文本**：
> ⭐ 固件发的是 `n0.val=4820*100/11865`，**让屏自己算百分比**
> （⭐ 官方 QA134 的推荐做法，省一条我们这边的除法）。
> ⚠️ 屏**不支持浮点**，所以必须"先乘 100 再除"。

---

## 三、⚠️ 字号 / 字库（最容易卡住的一步）

⚠️ **淘晶驰屏要先用上位机【生成字库】并下载到屏，否则中文不显示**（或显示成方块）。

🔴 **工程编码与字库编码都必须选 `UTF-8`**（⭐ 理由见使用说明 §2.1）。

### 3.0 ⭐⭐ 按字号分库（⚠️ 字库绑定了字号，⛔ 一个库出不了两种大小）

| 控件 | 字号 | ⭐ 需要哪些字符 | ⭐ 建哪个库 |
|---|---|---|---|
| `t0` 曲谱标签 | **24** | 中文 **`曲谱：`** | 库 ① |
| `g0` 曲谱名 | ⭐ **48** | ⭐ **ASCII** + ⭐ **日文假名**（见 §3.2） | 库 ② |
| `t1` 状态字 | ⭐ **48** | ⭐ 中文：**`待机 灌谱中 就绪 播放中 供数不足 断链 溢出 播完`** | 库 ②（⭐ 与 `g0` 合并） |
| `n0` 数字 | ⭐ **48** | ASCII 数字 | 库 ②（⭐ 同上） |
| `t2` 事件数 | ⭐ **32** | ⭐ 只有 ASCII（`0-9` `/`） | 库 ③ |
| `t3` 蓝牙 | ⭐ **32** | ⭐ 只有 ASCII（`BT OK --`） | 库 ③（⭐ 同上） |

⇒ ⭐ **只需 3 个字库**：
1. **24 号** —— 只放 `曲谱：`
2. ⭐ **48 号** —— ASCII + 假名 + 状态字中文（⭐ **合并省事**）
3. ⭐ **32 号** —— 纯 ASCII

> ⭐ **注意**：`t2`/`t3`/`n0` **全是 ASCII** ⇒ ⚠️ **⛔ 不用中文字库**（ASCII 字库必有）。

> ⚠️ **为什么 `g0` 和 `t1` 能合并**：⭐ 两者**同为 48 号** ⇒ 同一个库没问题
> （⭐ 字库里多几个用不到的字**不影响显示**，⚠️ 只多占一点 Flash）。

### 3.1 ⭐ 中文字要勾哪些（⭐ 共约 20 字）

```
曲谱：
待机 灌谱中 就绪 播放中 供数不足 断链 溢出 播完
```

> ⚠️ **原「喂不饱」已改成「供数不足」**（⭐ 书面说法，⚠️ 且与另两个故障语义并列清晰）：
> · `断链` = 🔴 **蓝牙链路断了**
> · **`供数不足`** = 🔴 **链路在，但数据没跟上**（`evt_underrun`）
> · `溢出!` = 🔴 **喂太快，FPGA 缓冲满了**

### 3.2 ⭐ 日文歌名要加的假名（⭐ 直接复制粘贴）

> 🔴 **官方明确**：**UTF-8 模式下不支持中文输入法**（QA103）
> ⇒ ⭐ **靠粘贴**，⛔ 别指望在字库工具里直接敲。

**一次全选版（推荐整行复制）**：

```
あいうえおかきくけこさしすせそたちつてとなにぬねのはひふへほまみむめもやゆよらりるれろわをんがぎぐげござじずぜぞだぢづでどばびぶべぼぱぴぷぺぽぁぃぅぇぉっゃゅょゎアイウエオカキクケコサシスセソタチツテトナニヌネノハヒフヘホマミムメモヤユヨラリルレロワヲンガギグゲゴザジズゼゾダヂヅデドバビブベボパピプペポァィゥェォッャュョヮー・「」（）〜
```

**分组的版本**（⚠️ **第 3 组最容易漏**）：

| 组 | 内容 |
|---|---|
| 平假名清音 | `あいうえおかきくけこさしすせそたちつてとなにぬねのはひふへほまみむめもやゆよらりるれろわをん` |
| 片假名清音 | `アイウエオカキクケコサシスセソタチツテトナニヌネノハヒフヘホマミムメモヤユヨラリルレロワヲン` |
| 🔴 **浊音/半浊音/小字/长音** | `がぎぐげござじずぜぞだぢづでどばびぶべぼぱぴぷぺぽ`<br>`ガギグゲゴザジズゼゾダヂヅデドバビブベボパピプペポ`<br>`ぁぃぅぇぉっゃゅょゎァィゥェォッャュョヮー・「」（）〜` |

> ⚠️ **第 3 组别漏**：日文歌名里 **`ー`（长音符）**、**`ッ`（促音）**、**`ャュョ`（拗音）**
> 出现频率极高，⛔ 只勾清音会缺字。

⚠️ **日文歌名常混「汉字 + 假名」** ⇒ ⭐ **CJK 汉字和假名都要勾**。

### 3.3 🔴 本屏 Flash 只有 4 MB

⛔ **别勾"CJK 全部"**（上万字，装不下）、⛔ **别勾"所有语言"**。

⭐ **推荐组合**：官方的 **《3500 日常字符集合.txt》** + **单独勾平假名/片假名**。

> ⭐ **做法**：上位机 → 工具 → 字库制作 → 🔴 **编码选 UTF-8** → 勾字号与字符 → 生成
> ⚠️ **生成后必须一起下载到屏**，否则那行字不显示。

⚠️ **如果嫌麻烦**：⭐ 把所有中文换成英文（`SONG:` / `EVT:` / `STATE:` / `BT:`），
就**完全不需要中文字库**。⚠️ 代价是演示观感差一点。

---

## 四、⭐⭐ 固件实际发的命令（⭐ 用来验证屏做对了）

> ⭐ **每条以 `0xFF 0xFF 0xFF` 结尾**（固件自动加，⛔ 不用你管）。
> ⭐ **与固件 `hmi.c` 逐条核对过**。

| 时机 | 固件发的命令 | 屏上应显示 |
|---|---|---|
| 曲谱名变化 | `g0.txt="09_Conjurer"` | ⭐ **滚动文本里出现歌名**（长名会滚动） |
| 进度变化 | `j0.val=45` | 进度条走到 45 |
| 进度变化 | `n0.val=4820*100/11865` | 数字显示 `40`（⭐ 屏自己算） |
| 进度变化 | `t2.txt="4820/11865"` | 事件数变了 |
| 状态变化 | `t1.txt="播放中"` | 状态字变了（⛔ 无 `状态：` 前缀） |
| 蓝牙变化 | `t3.txt="BT OK"` | 显示 `BT OK` |
| 蓝牙变化 | ⭐ **`t3.pco=2016`** | ⭐ **变绿**（已连接） |
| 蓝牙变化 | ⭐ **`t3.pco=63488`** | 🔴 **变红**（未连接） |

> ⭐ **`pco` 是【整个控件】的字体色** —— ⭐ **这正是 `t3` 必须独立的原因**
> （⚠️ 合并的话数字会跟着一起变色）。
> ⭐ 颜色代号（官方 HMI 颜色表）：**`GREEN = 2016`** · **`RED = 63488`** · `GRAY = 33840`。

---

## 五、⭐ 上电顺序（⚠️ 官方明确要求，⛔ 别省）

固件已经按官方要求实现了，但你**台面手动调试**时要照做：

```
1. 给屏上电（⚠️ VCC 必须 5V，⛔ 不是 3.3V）
2. 等屏启动完 —— ⭐ 屏会主动发 0x88 表示"启动成功"
3. ⭐ 先发一次 0x00 FF FF FF 清屏的串口缓冲（防上电杂波）
4. 之后才能发正式命令
```

⚠️ **不照做的后果**：上电瞬间串口引脚有杂波 ⇒ 屏已收到乱数据 ⇒
🔴 **第一条命令会被当成乱数据的延续而解析失败**（⚠️ 看起来像"屏没反应"）。

---

## 六、✅ 自检：屏做对了没有

| # | 怎么测 | 期望 |
|---|---|---|
| **1** | 发 `g0.txt="TEST"` + `FF FF FF` | ⭐ **滚动文本里出现 `TEST`** |
| **2** | 发 `j0.val=50` + `FF FF FF` | ⭐ 进度条走一半 |
| **3** | 发 `n0.val=7*100/10` + `FF FF FF` | ⭐ 数字显示 `70`（⭐ 验证屏会算） |
| **4** | 发 `t1.txt="播放中"` + `FF FF FF` | ⭐ 中文正常（⚠️ 不显示 ⇒ 字库没下进去） |
| **5** | 发 `t3.txt="BT OK"` + `FF FF FF` | ⭐ 显示 `BT OK` |
| **6** | 发 `t3.pco=2016` + `FF FF FF` | ⭐ **`BT OK` 变绿**（⭐ 验证变色命令） |
| **7** | 发 `t2.txt="4820/11865"` + `FF FF FF` | ⭐ 事件数显示 |
| **8** | 断电重启 | ⭐ 控件回到初值（⚠️ 正常，固件会在连上后重刷） |

> ⭐ **判据 3 最值得做**：它一次验证「**屏能算 + 数字控件能显示**」两件事。
> ⭐ **判据 6 也很关键** —— 它验证 `pco` 变色这条路走不走得通。

---

## 七、⚠️ 硬件接线（⭐ 电平已确认）

| 屏引脚 | 接到 | ⚠️ 注意 |
|---|---|---|
| **VCC** | ⭐ **5 V** | 🔴 **⛔ 不能接 3.3 V**（屏要 4.65~6.5 V） |
| **GND** | GND | 共地 |
| **TX** | ESP32 的 **RX** | ⭐ **信号 3.3 V ⇒ 可直连** |
| **RX** | ESP32 的 **TX** | 同上 |

| 本版（S3 / BLE） | 引脚 |
|---|---|
| 屏 UART | ⭐ **UART2：GPIO4 = TX / GPIO5 = RX** |
| 给 FPGA | UART1：GPIO17 / GPIO18 |

> ⭐ **关键区分**：**"信号 3.3 V" ≠ "供电 3.3 V"** ——
> ⚠️ 信号线直连没问题，🔴 **但 VCC 接 3.3 V 屏根本不亮**。

---

## 八、⚠️ 本清单的边界

| # | 说明 |
|---|---|
| **1** | ⚠️ **坐标是按 320×240 估的**，实际可能需微调（⭐ 拖控件时以不重叠为准） |
| **2** | ⚠️ **中文字库的具体操作步骤我没法代做** —— 上位机是 Windows GUI |
| **3** | ⚠️ **未在真屏上验证过** —— 本清单依据官方文档 + 固件实现推导 |
| **4** | ⭐ 若某控件显示不出来，**先查字库**（⚠️ 中文不显示 90% 是字库没下进去） |

---

## 附 · 关联

| 想看什么 | 去哪 |
|---|---|
| ⭐ 固件实现 | `esp32/ble/main/hmi.c` · `hmi.h` |
| ⭐ 固件的配置项 | `esp32/ble/main/ble_config.h`（第 10 节） |
| ⭐ BLE 版说明 | `esp32/ble/README.md` |
| ⭐ 串口屏官方文档 | http://wiki.tjc1688.com/ |
