hokuu1102/Gowin2026-PolySynth/bringup/05-焊接与通电检查清单.md

# 🔧 05 · 焊接与通电检查清单（左右板通用）

> **本文件位置**：`bringup/05-焊接与通电检查清单.md`
> **用途**：⭐ **照着打勾**。焊一块板就用一份，⛔ 不要凭记忆。
> **配套**：`bringup/04-基石板上板验证指南.md`（上板阶梯）｜
> `files/10-硬件/已画PCB网表核对.md`（**以网表为准**）｜
> `files/20-代码/已知问题与风险清单.md`（`K-64`/`K-65`）
> **日期**：2026-09-21

---

## 〇、⭐⭐ 三条铁律（先看这个）

| # | 铁律 | 为什么 |
|---|---|---|
| **1** | ⭐⭐ **先焊电源、通电验证后，再焊信号** | 电源有问题时，信号部分越少越好查；⚠️ 而且**焊错了能少拆** |
| **2** | ⛔ **通电时绝不插 FPGA 板** | 板子有问题时**保护 FPGA**（也保护你的电脑 USB 口） |
| **3** | ⭐ **上电前目检有无连锡** | 特别是 **SOIC-16 的相邻脚**（`MCP3208`/`TLC5916`）与 **0.5 mm 间距的座子** |

> ⚠️ 再加一条：⭐ **每焊完一个功能块就测一次**，⛔ 不要"全焊完再一起测"——
> 那样出问题时**分不清是哪一块**。

---

## 一、⭐ 焊前准备（⛔ 还没通电）

| # | 检查项 | ✅ |
|---|---|---|
| 1.1 | ⭐ **对照 BOM 点数**：元件种类/数量与 `files/10-硬件/采购与验证清单.md` 一致 | ☐ |
| 1.2 | ⭐ **确认板子方向**：丝印与原理图一致（⛔ 别把板子焊反） | ☐ |
| 1.3 | ⭐ **确认芯片方向**：`MCP3208`/`TLC5916` 的 **1 脚**位置（SOIC-16 有圆点/斜角标记） | ☐ |
| 1.4 | ⚠️ **确认极性元件**：`LED`（长短脚）、`电解电容`（正负）、`TVS` | ☐ |
| 1.5 | ⭐ **两个 8P 座分清**（⚠️ **`K-65`，最容易错**） | ☐ |

### ⚠️⭐ 1.5 详解：两个 8P 座**外形相同、针位不同**

| 座 | 针 1 | 针 2 | 针 3 | 针 4 | 针 5 | 针 6 | 针 7 | 针 8 |
|---|---|---|---|---|---|---|---|---|
| **`SPI_1`** | **`CS`** | GND | **`MOSI`** | GND | **`MISO`** | GND | **`MCP_CLK`** | GND |
| **`LED_1`** | **`LE`** | GND | **`LED_CLK`** | GND | **`SDI`** | GND | **`OE`** | GND |

> ⛔ **插错会不工作甚至损坏**（`SPI_1.1` = `CS`，而 `LED_1.1` = `LE`）。
> ⇒ ⭐ **你的方案：板子丝印 + 线上标记** —— 焊座子时就把丝印确认好。

---

## 二、⭐ 分步焊接（每步焊完就测）

### 第 1 步 · 电源部分（**只焊这些**）

| # | 内容 | ✅ |
|---|---|---|
| 2.1 | 焊**电源座**（`3V3` 输入的 4P 座）+ **去耦电容** | ☐ |
| 2.2 | ⚠️ **不焊任何芯片、不焊信号座** | ☐ |

**通电测试**（⚠️ ⛔ **不插 FPGA 板**）：

| # | 测量点 | 期望 | 实测 | ✅ |
|---|---|---|---|---|
| 2.3 | `3V3` 对 `GND` | **3.3 V ±5%**（3.14~3.47 V） | ____ V | ☐ |
| 2.4 | ⭐ **`3V3` 对 `GND` 电阻**（⛔ 断电测） | ⭐ **不短路**（应 > 100 Ω，典型 kΩ 级） | ____ Ω | ☐ |
| 2.5 | ⚠️ **电源指示灯**（若有） | 亮 | ☐ | ☐ |

> ⚠️ **若 2.3 不对** ⇒ ⛔ **停下**，先查电源。别继续焊。
> ⚠️ **若 2.4 短路** ⇒ ⛔ **停下**，找连锡。

### 第 2 步 · 数字芯片（`MCP3208` / `TLC5916`）

| # | 内容 | ✅ |
|---|---|---|
| 2.6 | 焊 `U1`（`MCP3208`，左手板）或 `U2`（右手板）—— ⭐ **先确认 1 脚方向** | ☐ |
| 2.7 | 焊 `U4`（`TLC5916`，左手板） | ☐ |
| 2.8 | ⭐ 焊**串阻**（33 Ω）与**上拉电阻** | ☐ |

**⭐⭐ 上拉电阻：⛔ 这里最容易搞反（`E9`/`E10`）**

| 电阻 | 网络 | ⭐ 焊不焊 | 为什么 |
|---|---|---|---|
| **`R11`** | `OE` 上拉 10K | ⭐⭐ **必须焊** | ⭐ 悬空即灭（`K-02`）；⚠️ **与 `R12` 方向相反，⛔ 不要一起省** |
| **`R12`** | `LE` 上拉 10K | ⚠️ **建议不焊** | ⚠️ 与 `TLC5916` **内部下拉方向相反** ⇒ 焊上会让 `LE` 上电为高 ⇒ ⚠️ **可能闪一次随机灯**（`K-64`） |
| **`R15`** | `CS` 上拉 10K（右手板） | ⭐ **焊** | 防 `CS` 悬空误选中 |
| **`R16`** | `MISO` 上拉 10K（右手板） | ⭐ **焊** | 从机未选中时防浮空 |

> ⚠️ **`E7`/`E8`（左手板飞线补上拉）**：
> 左手板 `MISO`/`CS` **没有上拉** ⇒ ⭐ 计划**飞线补 10 kΩ 到 `3V3`**
> （⭐ 与右手板 `R16`/`R15` 对齐；⚠️ 可用一根 10K 排阻一起补）。

### 第 3 步 · 连接器与机电件

| # | 内容 | ✅ |
|---|---|---|
| 2.9 | 焊 **`SPI_1`**（⚠️ 8P，**先确认丝印是 SPI 那个**） | ☐ |
| 2.10 | 焊 **`LED_1`**（⚠️ 8P，**别与 `SPI_1` 混**） | ☐ |
| 2.11 | 焊**供电座**（4P） | ☐ |
| 2.12 | 焊**霍尔传感器**（`HAL49E`）×8（左手板）—— ⚠️ **注意朝向** | ☐ |
| 2.13 | 焊**指示灯** `LED0~7` —— ⚠️ **注意极性** | ☐ |
| 2.14 | 焊**按键/编码器**（右手板） | ☐ |

### 第 4 步 · 复测

| # | 测量点 | 期望 | ✅ |
|---|---|---|---|
| 2.15 | `3V3` 对 `GND` | 仍 3.3 V，⛔ **不短路** | ☐ |
| 2.16 | ⭐ **`OE` 上电电平** | ⭐ **高**（= 关断，安全） | ☐ |
| 2.17 | ⚠️ **`LE` 上电电平** | ⚠️ 若**没焊 `R12`** ⇒ 应为**低**（✅ 好） | ☐ |
| 2.18 | `CS` / `MISO` 上电电平 | 高（有上拉）或高阻 | ☐ |

---

## 三、⭐⭐ 通电自检（⛔ **先不插 FPGA 板**）

| # | 检查项 | 期望 | ✅ |
|---|---|---|---|
| 3.1 | 各路电压 | `3V3` = **3.3 V ±5%** | ☐ |
| 3.2 | ⚠️ **上电是否闪一次随机灯** | ⭐ **可能闪一次**（`K-64`）⇒ **已知，⛔ 不是故障** | ☐ |
| 3.3 | ⭐ **灯是否常亮不灭** | ⛔ 不该常亮（若常亮 ⇒ `OE`/`LE` 有问题） | ☐ |
| 3.4 | 芯片**发烫** | ⛔ 不该烫（微温正常） | ☐ |
| 3.5 | ⭐ **静态电流**（若有电流表） | 应在**几十 mA** 量级（⛔ 不是几百 mA） | ☐ |

> ⚠️ **3.2 的判据很重要**：`K-64` 已确认
> **左手板 `LE` 的 10 kΩ 上拉与 `TLC5916` 内部下拉方向相反**
> ⇒ 上电瞬间 `LE` 为高会让**移位寄存器内容被锁存到输出**，
> 而上电时内容不确定 ⇒ ⭐ **可能闪一次随机灯**。
> ⇒ ⭐ **这是已知现象，⛔ 不要当成故障去查**（⭐ 而"不焊 `R12`"可以消除它）。

---

## 四、⭐ 接线核对（`K-65`，**以网表为准**）

> ⚠️ **实际 PCB 与文档有 3 处不一致** ⇒ ⭐ **接线/写驱动一律以网表为准**
> （网表 = `files/10-硬件/原理图/lefthand_board.tel` / `righthand_board_A.tel`）

| # | 项 | 文档旧口径 | ⭐ **实际（以网表为准）** | ✅ |
|---|---|---|---|---|
| 4.1 | 左手板 `SPI_1` | 7 针（含 `3V3`） | ⭐ **8 针 `XH2.54`**：`CS/GND/MOSI/GND/MISO/GND/MCP_CLK/GND`（⛔ **无 `3V3`**） | ☐ |
| 4.2 | 信号名 | `SPI_SCLK` | ⭐ **`MCP_CLK`**（经 **33 Ω** 串阻 `R14`） | ☐ |
| 4.3 | 左手板 `LED_1` | 未细化 | ⭐ **8 针**：`LE/GND/LED_CLK/GND/SDI/GND/OE/GND` | ☐ |
| 4.4 | ⭐ **供电** | 走 `SPI_1` | ⚠️ **走另一个 4P 座**（`SPI_1` 上**没有** `3V3`） | ☐ |

> ⛔ **插错会烧/不工作**：两个 8P 座**外形相同、针位定义不同**。
> ⭐ **对策**：**板子丝印 + 线上标记**。

---

## 五、⭐ 插 FPGA 板之前的最后确认

| # | 检查项 | ✅ |
|---|---|---|
| 5.1 | ⭐ **`3V3` 与 `GND` 不短路**（⛔ 断电测电阻） | ☐ |
| 5.2 | ⭐ **所有信号脚对 `GND` 不短路**（逐脚量一遍） | ☐ |
| 5.3 | ⭐ **`SPI_1`/`LED_1` 没插反**（对照丝印） | ☐ |
| 5.4 | ⭐ **供电极性正确**（⛔ 反接会烧芯片） | ☐ |
| 5.5 | ⚠️ **FPGA 板的 IO 电平与板子匹配**（都是 **3.3 V**） | ☐ |
| 5.6 | ⭐ 手边**没有金属杂物**搭在板上 | ☐ |

> ⭐ **5.1/5.2 是"保护 FPGA"的关键** —— ⚠️ 一个连锡就可能烧掉 FPGA 的一个 bank。

---

## 六、⚠️ 常见故障 → 先查什么

| 现象 | 先查 |
|---|---|
| **上电就烫** | ⛔ **立即断电**！查电源连锡、芯片方向 |
| **`3V3` 只有 1~2 V** | 负载短路 / LDO 坏 / 电容焊反 |
| **上电闪一次随机灯** | ⭐ **正常**（`K-64`）；想消除 ⇒ **不焊 `R12`** |
| **灯常亮不灭** | `OE` 没上拉 / `LE` 一直高 / `TLC5916` 焊反 |
| **`MISO` 读到全 0 或全 1** | `MISO` 浮空 ⇒ 补 10 kΩ 上拉（`E7`） |
| **`CS` 疑似被误选中** | `CS` 悬空 ⇒ 补 10 kΩ 上拉（`E8`） |
| **插上 FPGA 板后 FPGA 不工作** | ⛔ **立即断电**！查 5.1/5.2（短路） |
| **霍尔读数不变** | 霍尔朝向 / 磁铁距离 / `3V3` |

---

## 七、⭐ 记录（每块板填一份）

| 项 | 左手板 | 右手板 |
|---|---|---|
| 焊接日期 | ____ | ____ |
| `3V3` 实测 | ____ V | ____ V |
| `3V3`-`GND` 电阻（断电） | ____ Ω | ____ Ω |
| `R11`（`OE` 上拉）焊了？ | ☐ 是 | —— |
| `R12`（`LE` 上拉）焊了？ | ☐ 是（⚠️ 建议**不焊**） | —— |
| `R15`/`R16` 焊了？ | —— | ☐ 是 / ☐ 是 |
| `E7`/`E8` 飞线补上拉？ | ☐ 已补 / ☐ 未补 | —— |
| 上电闪灯次数 | ____ | ____ |
| 静态电流 | ____ mA | ____ mA |
| 异常现象 | | |
| 结论 | ☐ 通过 ☐ 待查 | ☐ 通过 ☐ 待查 |

---

## 附：相关文件

| 内容 | 去哪看 |
|---|---|
| 上板阶梯（通电 → I2S 波形 → 霍尔） | `bringup/04-基石板上板验证指南.md` |
| 上板方案与仪器 | `bringup/02-基石板上板验证方案.md` |
| ⭐ **网表核对（以它为准）** | `files/10-硬件/已画PCB网表核对.md` |
| `K-64`/`K-65` 原文 | `files/20-代码/已知问题与风险清单.md` |
| 采购与验证清单 | `files/10-硬件/采购与验证清单.md` |
| 画板注意事项 | `files/10-硬件/画板注意事项.md` |
