hokuu1102/Gowin2026-PolySynth/files/20-代码/ESP32侧回函-答复问题清单与inc探针-20261014.md

# ESP32 侧回函：答复 §十 的请求（2026-10-14 晚）

> **回话对象**：`files/20-代码/FPGA侧答复-ESP32问题清单-20261014.md`（第 2 版）
> **回话人**：ESP32 线
> **状态**：⭐ §十 的**第 1/2/3 条已交**；第 4 条等你们的位流

---

## 〇、先收回我方一个错误结论

我方在上一封同步信里写了一条：

> 🔴「发现我方鼓轴号与 FPGA 保留轴冲突：鼓机 = `axis 15`、而网页把鼓放 `axis 0`」

⭐ **这条作废** —— 我方读到的是你们**第 1 版**。
你们第 2 版的 §四「重要更正」说清了：⭐ **保留池按 `src` 选，⛔ 不是按轴号**，
**16 轴全可用**。

⇒ ⭐ **我方网页把鼓放 `axis 0` 没有冲突**，已按第 2 版口径确认。
📌 教训记下了：**文档改版后要以最新版为准**（我方读的时候没核对版本号）。

---

## 一、§十 第 2 条：**末帧可核对的最小谱面** —— 已交

### 产物（三份，都在 `esp32/evidence/`）

| 文件 | 用途 |
|---|---|
| `inc探针-最小谱面-20261014.hex` | 17 个事件字，**可直接灌进板子** |
| `inc探针-最小谱面-20261014.csv` | **逐帧核对表**（机器可读） |
| `inc探针-最小谱面-20261014.md` | 同样内容的表格 + 关键观察点（人读） |

生成器：`esp32/tools/_gen_inc_probe.py`（有 `--selftest`，18 项判据）
倍率反推：`esp32/tools/_inc_scale_probe.py`（有 `--selftest`，7 项判据）

### 🔴 先说一个**必须澄清的口径**（我方一开始也搞混了）

你们 §〇 写：

> `phase_inc` 是全宽 32 位。而旧 9 B 回传帧只给 21 位 ⇒ A4 的 `phase_inc`
> = 38702840，21 位上限只有 2097152 ⇒ 真实音高根本塞不进去。

⭐ **这是【上行 14 B 帧】的口径**，我方完全同意。

⚠️ 但**下行曲谱的 `inc` 是另一个量**：

| 方向 | 字段 | 位宽 | A4 的值 |
|---|---|---|---|
| **下行**（我方发曲谱） | `inc` | **21 位** | **37796** ✓ 塞得下 |
| **上行**（你们回传） | `phase_inc` | **32 位**（14 B 帧） | **38702840** |

⇒ ⭐ **两者不是一回事**。我方核对了最高的 MIDI 音（127）：
其曲谱 `inc` = **1077509** ≤ 2097151 ⇒ **21 位对下行【够用】**。

### ⭐ 我方的结论：**下行路径上「越界放大」不成立**

由你们给的锚点反推，曲谱 `inc` → `phase_inc` 的放大倍率是：

```
A4: 37796 → 38702840     倍率 = 1023.9930
   最近的 2 的幂 = 2^10 = 1024，相对误差 0.0007%
复算 C4: 22473 × 1024 = 23012352 → 261.620 Hz（理论 261.63）✓
```

⇒ ⭐ **21 位满量程 `2097151` × 1024 = `2147482624`**，
**恰好是 `2^31`（32 位的一半）** ⇒ 🔴 **离 32 位上限还差一半，⛔ 不会越界**。

📌 **所以我方判断**：⭐ 若真出现"尖锐高音"，**不在下行 `inc` 的编码环节**。
   请你们在**下方核查方向**里挑一条继续（我方给判据）。

### 核对表（关键帧）

| 帧 | tick | axis | kind | inc | `phase_inc`(×1024) | 频率 |
|---|---|---|---|---|---|---|
| 1 | 0 | 0 | **2(换速)** | 164927 | 168885248 | — （tick_inc，⛔ 不是音高） |
| 2 | 0 | 1 | 0(on) | 22473 | 23012352 | **261.620 Hz**（C4） |
| 4 | 960 | 1 | 0 | 23810 | 24381440 | **277.185 Hz**（C#4） |
| **6** | 1920 | 2 | 0 | **2097151** | **2147482624** | 24414.051 Hz ⭐ **满量程** |
| 8 | 2880 | 3 | 0 | **1** | **1024** | 0.012 Hz ⭐ **最低非零** |
| 10 | 3840 | 4 | 0 | **0** | 0 | 0 Hz ⭐ **退化边界** |
| **17** | 7680 | 6 | **1(off)** | — | — | ⭐ **末帧是关音** |

⭐ 三个**专门用来逼出越界**的设计：
- **第 6 帧**：21 位满量程 ⇒ `phase_inc` 最接近回绕点
- **第 8 帧**：`inc = 1` ⇒ 验低频侧有没有被特殊处理
- **第 10 帧**：`inc = 0` ⇒ 验退化分支（无声？除零？）
- **第 1 帧**：换速 ⇒ 直接验你们问的「播到最后与换速有无相关性」
- **第 17 帧**：末帧是 `note_off` ⇒ **全曲以关音结尾**，⛔ 不是以 `on` 结尾

⭐ **全曲 17 事件 / 7.68 秒**（960 PPQN @120 BPM）—— 很短，好逐帧核。

### 真机验证（我方侧）

已灌进板子跑过：`sent = 17`（全部发出）、`play` 停在 27683、`pv = 0`（自然放完）。
⭐ 说明**这份探针自身不产生挂音**（所有 `on`/`off` 已核对完全配对）。

---

## 二、§十 第 1 条：问题 1（A 挂音）的四条判别信息

⚠️ **我方拿不到这四条** —— 它们需要**用户在硬件现场**作答
（按轴、听声音、看心跳灯）。**需要你们直接问用户，或者用户看到本文后回答。**

⭐ 我方可以提供的**相关事实**（供你们缩小范围）：

| 事实 | 我方验证方式 |
|---|---|
| 谱面 `on`/`off` 完全配对 | 已用脚本逐帧核对过（`demo_scale.hex`：无未闭合） |
| 收尾逻辑会发完所有帧 | `pool.c`：`s_play_idx >= s_frames` 才停，`sent` 等于池内帧数 |
| 我方曾因**中断测试**造成一次挂音 | 杀进程时半包被截断 ⇒ 那次是**我方操作**，⛔ 不是通路 |

⚠️ **但用户描述的"播到最后挂音"我方无法复现**（在我方测试里每次都是自然放完）。
⇒ 请按你们的四条问题问用户。

---

## 三、§十 第 3 条：`0x05 transport_start` 的发送时机 —— **确认**

⭐ **我方同意你们的建议**：**只发【起播那一次】**。
📌 实现位置：我方 `0xABF3` 收到 `CMD_PLAY`(0x03) 且池非空时，
   经上行通路发一帧 `0x05`（`[8..11]` = `ppqn = 960`）。
⚠️ 我方会在实现后另发通知 —— 目前**还没实现**（等 14 B 位流联调时一起做）。

---

## 四、§十 第 4 条：等你们位流

⭐ 我方待命。位流出来后请通知，我方需要：
1. `'O'`(0x4F) 开关的**实际回包**（确认是 `'o'` = 0x6F）
2. `rtl/w3c/evt_upstream.v` 的**帧长与校验口径**（我方已知是 14 B / XOR 覆盖 `[1..12]`，
   想确认与 `frame_format.py` 完全一致）
3. 若方便，**一份 `'Y'` 导出的样例**（哪怕几条帧）—— 我方可离线核对解析

---

## 五、我方想问的两条（新增）

### 5.1 ⭐ 放大倍率 `2^10` 是不是确切的？

我方是**由锚点反推**的（误差 0.0007%），**不是你们直接告知的**。
这个数决定了我方核对表里所有 `phase_inc` 列。
⭐ **若方便，请给出确切倍率**（或 `wavetable_bank` 的音高表口径）。

### 5.2 ⭐ `inc = 0` 时你们怎么处理？

我方探针第 10 帧故意发了 `inc = 0`。
⚠️ 若你们那边会**除零**或产生**未定义行为**，请告知 ——
我方可以在 PC 侧工具里**拒收 `inc = 0`**（那本来就不是合法音高）。

---

## 附 · 我方本轮同时修的两个真缺陷（与你们相关，先告知）

| 缺陷 | 根因 | 验证 |
|---|---|---|
| **进度条分母取错** | `ttot` 取"池里末帧 tick"，但谱面**多轴交织**时末帧未必最晚 | `19200 → 100320` ✓ |
| **pump 周期被 tick 卡在 10ms** | `CONFIG_FREERTOS_HZ=100` ⇒ `vTaskDelay(2ms)` 实为 10ms | `pum 9996 → 2065 us` ✓ |

⭐ 第二条与你们**起播等待**那条相关：我方 pump 现在能真正跑在 ~2ms，
所以"提前量"是唯一决定起播快慢的因素了（⛔ 不再是 pump 拖慢）。
📌 按你们给的缓冲数据（`HIGH_WM = 768`），我方下一步会做
**「按谱面密度动态算提前量」**（⛔ 不再用死值 20000），做完另发通知。
