hokuu1102/Gowin2026-PolySynth/files/20-代码/串口屏显示清单与EC11映射-20261016.md

# 串口屏显示清单与 EC11 映射（纯梳理，2026-10-16）

> 🔴🔴 **本文已被取代，不要再按本文实施。**
> **现行规格**：`files/20-代码/串口屏方案-定稿-20261018.md`
>
> 本文保留的价值只剩两项：
> - 第二/三节的 **1024x600 坐标与尺寸算法**（摆屏 1/屏 2 时可参考）
> - 各节引用的 **RTL 事实与行号**（查证用）
>
> ⛔ 本文中与定稿冲突的内容一律作废，包括：三屏划分、混响节点、
> 屏本地翻掩码、EC11 按压切对象、屏 3（标定+调试）。
>
> 本文性质：只读梳理 + 方案建议。未改任何 `rtl/` / `tb/` / `.ps1`（全量回归 `pwsh-1163` 在跑）。
>
> 触发需求（用户原话）：
> > "效果器的参数还是希望能用 EC11 手拧增减，但是可能需要配合串口屏。
> > 现在先梳理一下串口屏需要显示的内容。比如指板模式、滑音 on/off、当前起始音、BPM、效果器链等等参数。
> > 先列出来内容，不一定要放在一个屏幕上"
>
> 本轮（第二轮）修订，用户拍板 3 条：
> 1. 屏 7 寸（尺寸已定，按 1024x600 重算三屏全部坐标）。
> 2. 音量颤音也由推子调，推子应该能切到"音量颤音"这一档。
> 3. 屏 2 要体现"效果器链的链"，这是能体现特点的地方。
>
> 上一轮（第一轮）已拍板 5 条，仍然有效：
> 1. 页数可以集合一点。
> 2. 屏直接接 FPGA 的 `D14`/`D15`，不走 ESP32 中转。
> 3. 推子负责颤音与实时变调，EC11 负责效果器程度参数，两者是不同域，不冲突。
> 4. 专门做一页效果器链，点击某个参数的控件就激活 EC11 对该参数的调节。
> 5. 本文不用任何 emoji 或装饰符号。
>
> 第三轮修订（本轮），用户拍板 1 条，落实为 3 处：
> 1. "效果器链里面也保留音量颤音这个大块吧，点到这个的时候推子自动切换到音量颤音档位"。
>    落实为：链式图保留 5 个节点（含音量颤音），音量颤音节点自带 depth / rate 两个控件；
>    点这个节点（或它的 depth / rate 控件）就发一条"推子切到档 2"的命令，节点高亮，之后由推子连续扫。
>    EC11 目标清单**定为 6 个**（gain / trim / chorlen / dlylen / fb / mix），depth / rate 归推子档 2。
>
> 第四轮修订（本轮），用户拍板 1 条，落实为 2 处：
> 1. "点失真/合唱/延迟，高亮代表开启，再点一下表示关闭。总之就是点一下就翻转状态，不能只有参数调节"。
>    落实为：点**节点标题** = 翻转该效果器开/关（屏本地翻转掩码对应位，再用**现有的** `71 10` 帧整帧写出），
>    高亮 = 开启；点**参数控件** = 设 EC11 目标。音量颤音节点没有开关，点它只做"推子切到档 2"。
> 2. "不一定要实现翻转，我的意思是状态翻转。反正能实现功能就行了"。
>    落实为：**不新增任何协议、不新增任何寄存器**。屏 2 这一页的交互全部复用现有帧
>    （参数写入用 `71 11..18`，开关用 `71 10`）；凡需要动 rtl 的，一律标成"下一轮可选增强"，
>    不塞进最小可用第一步（见第八节）。
>
> 取证方式：逐个 `grep` / `read` 代码，不照抄任务书给的起点信号（其中两条已与代码不符，见 1.3）。
>
> 代码基线：`rtl/top.v` 7130 行。本轮刚落地 bit6 逐事件引导、心跳灯三态、键14 音高归零、方案B、指板多弦、延迟 send-return、失真 x256 加 `drive`、合唱下界 129。

---

## 〇、一句话结论

| 问 | 答 |
|---|---|
| 屏要显示什么 | 30 条运行时状态（见第一节全表）。按使用场景分 3 屏：演奏加节奏 / 效果器链 / 标定加调试。 |
| 屏尺寸 | 已定：7 寸，1024x600。全部坐标按此重算（第二节）。 |
| EC11 现在调什么 | 只有 2 个对象：`enc_obj_r = 0` 调 BPM，`= 1` 调变调。按压换对象。已接线并可用（`top.v:757-796`）。 |
| EC11 改成调什么 | 由屏点选目标，**定为 6 个**（失真 / 合唱 / 延迟 的 gain / trim / chorlen / dlylen / fb，加两级共用的 mix，见 4.2）。EC11 只增减当前目标，对象寄存器不必扩到 11 个，只要"屏指定的那一个"。 |
| 推子调什么 | 三个档：档 0 = 变调，档 1 = 音高颤音（上电默认），档 2 = 音量颤音（本轮新增，需要改 `fader_gear`，见第五节）。 |
| 点哪里决定谁来调 | 点效果器**节点标题** = 翻转该效果器开/关（高亮 = 开、灰 = 关，并带文字）；点**参数控件** = 设 EC11 目标。三条通路互相独立，见 2.2.3。 |
| 开关翻转怎么发帧 | **不新增协议**：屏本地维护掩码缓存，点击时翻转对应位，再用**现有的** `71 10 <新掩码> FF FF FF` 整帧写出（该帧早已实现，见 `uart_ui.v:428-430`）。风险一行：掩码没有回读时屏的缓存可能过期，见 6.5。 |
| 档 2 的两条进入方式 | 推子自己的切档循环（串口 `'J'` / 矩阵 idx 5）与屏点选（`65 09 FF FF FF`，**下一轮可选增强**），两条写**同一个寄存器** `fader_gear.gear_o`，见 5.5。 |
| 最大的问题 | FPGA 到屏的"值回读"通路完全不存在。`uart_ui` 的发送口被接成 `tx_busy_i = 1'b1`（`top.v:1217`），而且该模块内部根本没有发送状态机（见 3.2）。屏上显示的所有数字都只是它自己发过的缓存。 |
| 第二大的问题 | BPM 在 FPGA 里没有数字寄存器。tempo 状态只有 `play_seq.tick_inc_o`（32 位相位增量，`top.v:2521`）。屏上要显示"BPM = 120"，必须先加一个 BPM 寄存器（见 6.4）。 |
| 与 2026-10-14 裁定的关系 | 不冲突，是不同域。那次裁定说效果器参数不用 EC11、改走推子参数页；本次把"音量颤音"明确划给推子档 2，EC11 只负责失真/合唱/延迟的程度参数。三组目标寄存器完全不重叠（见 5.1 核验）。 |

---

## 〇之二、2026-10-18 屏幕方案（**当前定稿，以此为准**）

> ⚠️ **本文件是工作草稿，不是权威**（用户原话："这个文档不一定正确啊，我后续还会改一下"）。
> 本节是 2026-10-17~18 两轮裁定的**合并定稿**，前文与本节冲突时**以本节为准**。
>
> | 本节的项 | 性质 |
> |---|---|
> | **A / B / C / D / E / G / H / I** | ✅ **用户已拍板**，是决定 |
> | **F**（控件号）· **J**（交付清单） | ⚠️ **提案**，等屏侧（队友）确认或替换 |

### A. 只保留 **2 屏**（原"屏 3 标定+调试"整屏取消）

| 屏 | 内容 |
|---|---|
| **屏 1** | 演奏 + 节奏（音色/模式/BPM/鼓机/looper 等只读状态） |
| **屏 2** | **效果器链**（本节重点） |

⛔ **原屏 3（标定 + 调试）整个不要了** —— 用户原话："感觉整个屏 3 都没必要了"。

### B. 屏的角色：**显示 + 开关 + 选对象**（⭐ 已修正）

> 🔴 **修正 2026-10-18**：上一版写的"屏纯显示、不参与改值"**作废**。
> 用户原话：*"没有 EC11 按压这个动作，所有的开关交给串口屏的交互，点一下打开，再点一下关闭"*

| 动作 | 谁做 |
|---|---|
| **开 / 关**（失真·合唱·延迟） | ⭐ **点屏上那个节点**：点一下开，再点一下关 |
| **选中对象** | 同上，**点谁就选中谁**（节点高亮） |
| **改参数值** | **EC11 旋转**（失真/合唱/延迟的 gain/trim/chorlen/dlylen/fb/mix） |
| **两个颤音的深度/速率** | **推子**（档 1 / 档 2） |
| **变调** | **推子**（档 0） |
| **推子档位** | 点颤音/变调节点 ⇒ 推子**自动切到对应档** |

⛔ **EC11 没有"按压"这个动作** —— 它只旋转。⛔ 屏上不要做"点参数块 = 设 EC11 目标"之外的东西。

### C. ⭐ 切换效果器时：**原效果器保持开启**

> 用户原话：*"如果按了一个效果器，没有把他按关就按另一个效果器的话，
> 直接切换到另一个效果器的档位，原来的效果器仍然保持开启"*

```
点 [失真]（关→开，选中失真，EC11 目标是 gain）
点 [合唱]（关→开，选中合唱，EC11 目标变成 chorlen）
   ⇒ ⭐ 失真【仍然开着】，不会因为"你去看合唱了"就关掉 ✅
```

⇒ 屏上**必须同时显示所有节点的开关状态**（不能只高亮当前那个）。

### D. 效果链的显示顺序（⭐ 最新）

```
音高颤音 → 失真 → 合唱 → 延迟 → 音量颤音
```

| 节点 | 开关 | 参数 | 谁调 |
|---|---|---|---|
| **音高颤音** | 无（深度 0 = 关） | 深度 · 速率 | **推子档 1** |
| 失真 | ✅ 点节点翻转 | 增益 gain · 补偿 trim | EC11 |
| 合唱 | ✅ 点节点翻转 | 长度 chorlen | EC11 |
| 延迟 | ✅ 点节点翻转 | 长度 dlylen · 反馈 fb | EC11 |
| 合唱/延迟 | — | **干湿 mix（两级共用）** | EC11 |
| **音量颤音** | 无（深度 0 = 关） | 深度 · 速率 | **推子档 2** |

⚠️ **没有混响节点**（不做）。⚠️ 音高颤音画最左是**准确的**（它在振荡器域，物理上在整条链之前）。

### E. 两个颤音**可以共存**

- 切档时**保持**另一个的值（⛔ 不清零）
- 屏上**同时**显示两个颤音各自的深度/速率
- 关掉某个颤音 = **在它自己那一档把推子推到 0**
- ⭐ **解锁 = 立即采用推子当前位置**（用户裁定："置零就是不要这个效果"）

### F. 参数控件：⭐ **圆形旋钮式进度条**（模仿真实旋钮）

> 用户原话：*"效果器的参数最好用圆形的旋钮式进度条模仿真实旋钮（如果有的话）"*

- 优先用屏控件的**圆形/表盘类控件**（淘晶驰若提供"表盘/指针/圆弧进度条"就用它）
- 退而求其次：**圆弧形进度条**（画一段弧，按比例填色）
- 再退：普通横向进度条
- ⚠️ 若屏控件库没有圆形，**如实告知**，不要硬画

### G. 屏上**不要**出现的东西（⭐ 逐条确认）

| ⛔ 不要 | 原因 |
|---|---|
| **Test Mode 入口** | 控制板已有对应按键（用户："串口屏也不需要测试模式入口了，因为控制板已经有了"） |
| **引导模式** | 完全由上位机灌谱决定，与 FPGA 关系不大（用户原话） |
| **屏 3 整屏** | 没必要 |
| **混响节点** | 不做 |
| **EC11 按压动作** | 没有这个动作 |
| **"起始音"独立显示** | 用户："起始音和变调感觉差不多" ⇒ 合并进变调/不单独占位 |
| 滑条 / 输入框 / 加减按钮 | 值只由 EC11 / 推子改 |

### H. 鼓机节奏型：用**罗马数字 I II III IV**

> 用户原话：*"鼓机节奏型不用写这么复杂，罗马数字1234吧"*

⇒ 屏上只显示 `I` / `II` / `III` / `IV`，⛔ 不要画节奏型图形、不要写拍号细节。

### I. FPGA → 屏 的推送策略：**S1 + S2**

| 编号 | 策略 |
|---|---|
| **S1** | **按需推送**（值变化才发；⛔ 不周期刷） |
| **S2** | **总开关**（一个串口命令开/关推送；调试时关掉） |

理由：屏和 PC 调试终端**共用同一个串口**。用户补充："其实以后屏接好了一般都不需要串口调试了" ⇒ S2 默认**开**。

### J. 帧格式与控件号（⚠️ **提案，待队友确认**）

**TJC 标准文本指令，每条以 `FF FF FF` 结尾**：`<控件名>.txt="<文本>"` FF FF FF

| 链上位置 | 显示内容 | 建议控件名 | 示例 |
|---|---|---|---|
| 音高颤音 | 深度 / 速率 | `p_d` / `p_r` | `p_d.txt="0.42"` |
| 失真 | 开/关 / 增益 / 补偿 | `d_on` / `d_g` / `d_t` | `d_on.txt="开"` |
| 合唱 | 开/关 / 长度 | `c_on` / `c_l` | `c_l.txt="15ms"` |
| 延迟 | 开/关 / 长度 / 反馈 | `l_on` / `l_l` / `l_f` | `l_f.txt="0.38"` |
| 干湿（共用） | mix | `m_x` | `m_x.txt="0.50"` |
| 音量颤音 | 深度 / 速率 | `v_d` / `v_r` | `v_v.txt="0.00"` |
| 状态条 | 当前对象 / 推子档 | `cur` / `gr` | `gr.txt="音量颤音"` |

**触摸控件号（`65 <号> 01 FF FF FF`）**

| 号 | 点它做什么 |
|---|---|
| `0` | 模式 指板/钢琴（现有，屏 1） |
| `9` | 选中【音量颤音】⇒ 推子切档 2 |
| `10` | 选中【音高颤音】⇒ 推子切档 1 |
| `11` | 选中【变调】⇒ 推子切档 0 |
| `12` / `13` | 失真：翻转开关 / 选中增益 |
| `14` | 合唱：翻转开关 + 选中长度 |
| `15` / `16` | 延迟：翻转开关 / 选中反馈 |
| `17` | 干湿 mix 选中 |

⚠️ **控件号是两边契约**，改一个要两边同改。队友若已占用某些号，请回一份实际占用表。

### K. 给队友的交付清单

1. **2 屏**：演奏+节奏 / 效果器链（7 寸 1024x600）
2. **效果链页**：5 个节点，顺序 **音高颤音 → 失真 → 合唱 → 延迟 → 音量颤音**（⛔ 无混响）
3. **点节点 = 翻转开关 + 选中**（⛔ 没有 EC11 按压）
4. **参数用圆形旋钮式进度条**（没有就如实说）
5. **鼓机节奏型用 I/II/III/IV**
6. **⛔ 不做**：Test Mode 入口、引导模式、屏 3、混响、滑条/输入框
7. **波特率 500000 8N1**（⛔ 不是 115200）

---

## 一、用户可见状态全表

回读三档标记：
- 无：屏拿不到真实值，只能显示本地缓存，不可信（见第七节）
- 间接：有"命令受理回执"或"事件计数"，但回包里不含值
- 有值：真能把值读回来

### 1.1 模块层信号（`top.v` 的 `generate` 之外，新模块可直接读）

| # | 信号 | 文件:行号 | 取值域 | 当前默认 | 谁改它 | 回读 |
|---|---|---|---|---|---|---|
| 1 | `play_fretboard_mode` | `rtl/top.v:1255`（等于 `~ui_mode_piano`） | 1 位，1=指板 / 0=钢琴 | 0（钢琴），来自 `uart_ui.MODE_PIANO_DEFAULT=1`（`top.v:1198`） | 屏触摸控件 0、串口 `'A'`、矩阵模式键 | 无 |
| 2 | `slide_on_r` | `rtl/top.v:599-603` | 1 位 | 0（关） | 串口 `'W'`（`calib_cmd.v:211`） | 无 |
| 3 | `transpose_semi` | `rtl/top.v:969` 声明，`:2952` 驱动 | `signed [4:0]`，-12..+12 | 0（`fader_gear.enc_r` 复位 `5'd12`，`:223`） | 推子 CH2/CH3（仅档 0）、串口 `'F'`/`'G'`/`'H'`、EC11（对象=变调）、矩阵键14 音高归零 | 无 |
| 4 | `ui_base_semi` | `rtl/top.v:1158`，`:1227` | `[6:0]`，只认 0 / 12 / 24 | 0（C4，`uart_ui.v:294`） | 屏 `RET_NUM` 变量 1（屏要发 `0 / 24 / 48`，`uart_ui.v:415-419`） | 无 |
| 5 | `timbre_sel_r` | `rtl/top.v:657` 声明，`:798-803` | 2 位，0..3 | 0（BASS） | 串口 `'I'`（`calib_cmd.v:131`）、直连音色按键 `timbre_btn_down`（`top.v:689-691`） | 无 |
| 6 | `met_on_r` | `rtl/top.v:576-580` | 1 位 | 0（关） | 串口 `'B'`（`calib_cmd.v:135`） | 无 |
| 7 | `drum_pattern_r` | `rtl/top.v:890-894` | 2 位，0..3 | `DRUM_PATTERN_INIT = DRUM_PATTERN_ID`（`:888`） | 串口 `'D'`（`calib_cmd.v:147`） | 无 |
| 8 | `key_drum_r` | `rtl/top.v:902-906` | 1 位 | 0（关） | 串口 `'K'`（`calib_cmd.v:162`） | 无 |
| 9 | `guide_only_r` | `rtl/top.v:646-650` | 1 位 | 0（关，普通演奏） | 串口 `'U'`（`calib_cmd.v:231`） | 无 |
| 10 | `scope_mode_r` | `rtl/top.v:2056-2064` | 2 位，0=波形 / 1=李萨如 / 2=FFT | 1（李萨如），来自 `SCOPE_MODE=1`（`top.v:351`） | 串口 `'E'`（`calib_cmd.v:187`） | 无 |
| 11 | `enc_obj_r` | `rtl/top.v:758-762` | 1 位，0=BPM / 1=变调（本轮计划扩到 2 位，加"2=屏选参数"） | 0（BPM） | EC11 按压（`enc_sw_down_w`）、屏点选（计划） | 无（但已给灯 5，`top.v:7073`） |
| 12 | `led_gear_st` | `rtl/top.v:1732`，`:2951`（来自 `fader_gear.gear_o`） | 2 位，0=变调 / 1=音高颤音 / 2=音量颤音（本轮新增）/ 3=无 | 1（音高颤音，`fader_gear.v:224`）；`g_silent` 档为 `2'd3`（`:2115`） | 串口 `'J'`、矩阵 idx 5 | 有值（已导出给灯 3） |
| 13 | `led_looper_st` | `rtl/top.v:1733`，`:5379-5381` | 2 位，0=空闲 / 1=录音 / 2=回放 / 3=武装中 | 0 | 串口 `'R'`/`'L'` 加 `lp_recpend_w` | 有值（已导出给灯 4） |
| 14 | `ui_fx_mask` | `rtl/top.v:1166`，`:1233` | 8 位，只 bit0/1/2 有效（失真/合唱/延迟） | 0（全关），来自 `FX_EN_MASK`（`top.v:57`） | 屏或串口助手帧 `71 10 <v> FF FF FF` | 无 |
| 15 | `ui_fx_gain` | `:1167`，`:1234` | 16 位 Q4.12，字节乘 256 | 16384（4.0 倍） | 帧 `0x11`、EC11 目标 0 | 无 |
| 16 | `ui_fx_trim` | `:1168`，`:1235` | 16 位 Q1.15，字节乘 256 | 8192（0.25） | 帧 `0x12`、EC11 目标 1 | 无 |
| 17 | `ui_fx_mix` | `:1169`，`:1236` | 8 位 Q0.8 | 128 | 帧 `0x13`、EC11 目标 5 | 无 |
| 18 | `ui_fx_fb` | `:1170`，`:1237` | 8 位 Q0.8 | 96 | 帧 `0x14`、EC11 目标 4 | 无 |
| 19 | `ui_fx_depth` | `:1171`，`:1238` | 8 位 | 0（数值恒等） | 帧 `0x15`、推子 CH2（档 2；屏点音量颤音节点即进入该档，见 2.2.3） | 无 |
| 20 | `ui_fx_rate` | `:1172`，`:1239` | 8 位 | 7 | 帧 `0x16`、推子 CH3（档 2；同上） | 无 |
| 21 | `ui_fx_dlylen` | `:1173`，`:1240` | 14 位，字节乘 128 采样 | 8192 采样（168 ms） | 帧 `0x17`（上限 16383，`uart_ui.v:470`）、EC11 目标 3 | 无 |
| 22 | `ui_fx_chorlen` | `:1174`，`:1241` | 11 位，字节乘 32 采样 | 736（23 乘 32，15 ms） | 帧 `0x18`（上限 2047，`uart_ui.v:480`）、EC11 目标 2 | 无 |
| 23 | `ui_test_mode` / `_n` | `:1179-1180`，`:1243-1244` | 1 位加 2 位，档 4/8/16/32 | 0 / 00 | 屏触摸控件 2 | 无，而且它只是镜像，非权威（`top.v:2224-2225`） |
| 24 | `ui_frame_cnt` / `ui_resync_cnt` / `ui_err_cnt` | `:1181`，`:1246-1248` | 16 位饱和 | 0 | 屏帧解析（`uart_ui.v:177-179`） | 间接（已导出但无消费者，会被剪） |
| 25 | `ui_hb_ready` | `:1182`，`:1249` | 1 位 | 0 | 屏发 `0x88` 握手（`uart_ui.v:350-352`） | 间接（已导出但无消费者） |
| 26 | `fault_sticky` | `rtl/top.v:6716-6719` | 1 位，sticky（只复位才清） | 0 | `fault_any_w`（`:2845`） | 有值（已导出，驱动心跳灯快闪） |
| 27 | `ovf_any` | `rtl/top.v:1905`，`:5703-5704` | 1 位 | 无 | 8 个源取或（`ee_ovf` / `ee_lost` / `sa_overflow` / `looper_overflow` / `mg_overflow` / `txf_ovf` / `eb_ovf` / `eb_drop`） | 有值（已并入 `fault_sticky`） |

### 1.2 `g_sound` 内的状态（必须新引线才能给屏）

结构性事实：`top.v` 的 `generate` 从 `:2078` 到 `:6538`，`g_sound` 从 `:2155` 起。凡是只在 `g_sound` 里声明的信号，`generate` 外的模块读不到。这正是 `led_gear_st` / `led_looper_st` / `led_beat` 当初被特意上提到模块层的原因（`top.v:1719-1734`）。给屏加字段就是重复这个动作。

| # | 信号 | 文件:行号 | 取值域 | 当前默认 | 谁改它 | 回读 |
|---|---|---|---|---|---|---|
| 28 | BPM（不存在） | `ps_inc32` 等于 `play_seq.tick_inc_o`（`:2418` 声明，`:2521`） | 32 位相位增量，等于 BPM 乘 1374 加 47 | 164927（120 BPM，`play_seq.v:289` 的 `TICK_INC_DEFAULT`） | 串口 `'Q'`（过小节对齐器 `bpm_bar_quant`，`:2438-2447`）、EC11 加减 1（`enc_bpm_up_w`，`:2537`）、曲谱 `kind=2` 事件 | 无数字 |
| 29 | `at_done` | `:3041` 声明，`:3250` | 1 位 | 0 | `'T'` 自动零点完成 | 间接（回单字节 `'T'`，`:3709`，不含状态） |
| 30 | `at_skip` | `:3170`，`:3247` | 8 位位图 | 0 | `calib_autotare` 跳过某轴 | 无（只取或进 `fault_any_w`，`:3180`） |
| 31 | `at_fail` | `:3171`，`:3248` | 1 位 | 0 | `calib_autotare` | 无（同上） |
| 32 | `sp_cur_axis` / `sp_busy` / `sp_reject` | `:3162-3163`，`:3508-3510` | 4 位加 1 位加 1 位 | 0 | 串口 `'S'` | 有值：`'V'` 回 `V<state><axis><rej_hi><rej_lo>` 加 CRLF（7 字节，`span_probe.v:33`）；`'P'` 回 `P<ch>` 加 4 位十进制加 CRLF（8 字节，`pos_probe.v:25`） |
| 33 | `af0_pol` / `af1_pol`（ADC 原始码） | `:3315` | 12 位，0..4095 | 上电 tare 后约 2000..2900（实测见 `top.v:287-292`） | 霍尔加 ADC | 有值：`'P'`（全通道轮转）、`'N'`（逐轴，自动切轴，`:4279`） |
| 34 | `ps_cur_tick`（音乐位置） | `:2423`，`:2546` | 20 位 | 0 | free-run（`run_i=1'b1`） | 无消费者 |
| 35 | `bg_bar_cnt`（小节计数） | `:2369`，`:2578` | 16 位 | 0 | free-run | 无消费者，被综合剪掉 |
| 36 | `bg_tick_cnt` | `:2365`，`:2574` | 16 位 | 0 | free-run | 有值（有消费者：鼓机 `:2708`、looper `:5242`） |
| 37 | `bg_beat`（拍点脉冲） | `:2367`，`:2381` | 1 位脉冲 | 无 | free-run | 有值（已导出为 `led_beat` 给灯 3） |
| 38 | `bpm_pending_obs` | `:2436`，`:2446` | 1 位 | 0 | `'Q'` 已请求、等小节线 | 无消费者，被剪 |
| 39 | `ps_tempo_applied` | `:2419`，`:2527` | 1 位脉冲 | 0 | 换速生效 | 无消费者，被剪 |
| 40 | `ps_underrun`（供数不足） | `:2420`，`:2528` | 1 位 | 0 | 曲谱缓冲空 | `top.v` 内无消费者（ESP32 侧另有 `evt_underrun`） |
| 41 | `nm_active` 等于 `voice_active_o`（32 路占用位图） | `:2176`，`:5982` | 32 位 mask | 0 | `note_manager` | 有值（有消费者：mixer `:6324`） |
| 42 | `mx_n_active`（复音占用数） | `:2213`，`:6334` | 6 位，0..32 | 0 | `tdm_render_mixer.n_active_o`（`tdm_render_mixer.v:571`） | 只有 2 处出现（声明加端口映射），无消费者，被综合剪掉 |
| 43 | `nm_gate`（32 路按住位图） | `:2175`，`:5981` | 32 位 mask | 0 | `note_manager` | 有值（有消费者） |
| 44 | `loop_rec_on_r` / `loop_play_on_r` | `:5070-5071`，`:5114-5125` | 1 位加 1 位 | 0 / 0 | 串口 `'R'` / `'L'` | 间接（经 `led_looper_st`） |
| 45 | `looper_evt_cnt`（已录事件数） | `:5093`，`:5293` | 16 位 | 0 | 录音中累加 | 有值（有消费者：`rec_dump` `:5347`） |
| 46 | `looper_layer_state` | `:5092`，`:5286` | 1 位（0=空闲 / 1=录或放） | 0 | `looper.v:1593` | 有值（有消费者） |
| 47 | `af_fault` / `mx_fault` | `:2784` 加 `:2813`，`:2209` 加 `:6333` | `[ADC_N-1:0]` / 1 位 | 0 | ADC SPI 故障 / mixer 超时 | 无（只取或进 `fault_any_w`，`:2845`） |
| 48 | `tm_enable_r` / `tm_n_code_r`（Test Mode 权威状态） | `:2232-2233`，`:2245-2246`、`:2287-2288` | 1 位加 2 位 | 0 / 00 | 串口 `'M'` 或屏控件 2（`:2252`） | 间接（回单字节 `'4'`/`'8'`/`'A'`/`'B'`/`'0'`，`:3646-3651`；注意 `TEST_MODE_EN=0` 时回 `'-'`） |
| 49 | `as_seen`（16 轴"见过"位图） | 真实声明在 `:3111` 附近（`top.v:1802` 注释引用） | 16 位 | 0 | `axis_snapshot` | 无（只经 `adc_partial_w` 取或进 `fault_any_w`，`:1810-1817`） |
| 50 | 各轴 `tare` / `span`（零点 / 满程） | `calib` / `calib_span` 内部 | 12 位乘 16 轴 | 上电自动 tare | `'T'` / `'S'` | 不可读（`'P'`/`'N'` 读的是校正后的 pos 或原始码，不是 zero/span 本身） |

### 1.3 起点核对：任务书给的两条与代码不符

| 任务书写 | 代码事实 |
|---|---|
| `base_semi` / `base_oct_r` | `base_semi` 是 `uart_ui` 的输出（`top.v:1158`）；`base_oct_r` 在 `note_manager.v:459-467`，只认 0/12/24，其余回 0。所以屏必须发 `0/24/48`（`uart_ui.v:36`）。 |
| `transpose_semi`（`fader_gear.enc_r`，12 = 不调） | 正确。但 `fader_gear` 的内部编码 `enc_r` 是 0..24（12 = 不调），输出才是 `signed -12..+12`（`fader_gear.v:249`）。屏上显示哪一个必须说清（本文建议显示 `transpose_semi`）。 |
| `enc_obj_r`（EC11 对象：0=BPM，1=音高） | 正确。注意 `top.v:758` 写"1 = 变调"、`led_indicator.v:107` 写"1 = 音高"，是同一个东西的两种叫法，不是矛盾。 |

---

## 二、分屏设计（3 屏，7 寸 1024x600）

> 🔴🔴 **2026-10-18 已改为【2 屏】** —— 本节及以下 2.1~2.5 是**三屏时代的推导**，
> 只作为**坐标/尺寸的参考**保留。
> ⛔ **屏 3（标定+调试）整个取消**（用户原话："感觉整个屏 3 都没必要了"）。
> ✅ **当前定稿见 〇之二**（2 屏、链顺序、开关交互、旋钮式控件、去掉 Test Mode/引导模式）。
> 📌 本节的 1024x600 尺寸与坐标算法**仍然有效**，可继续用来摆屏 1/屏 2。

### 2.0 尺寸与算账（尺寸已定）

屏尺寸已定：7 寸，分辨率 **1024 x 600**（`files/30-方案决策/产品形态决议清单.md:644` 写 X2 7 寸；`files/10-硬件/采购与验证清单.md:339` 写 X2 7.0 寸 1024x600，两者一致）。

全部三屏按同一套基准重算：

| 项 | 值 |
|---|---|
| 分辨率 | 1024 x 600 |
| 顶部常驻状态条 | y 0..36（高 36，每屏都有，见 2.5） |
| 可用高度 | 600 减 36 = 564（y 36..600） |
| 32 号字 | ASCII 16 px，中文 32 px，行高 64 |
| 24 号字 | ASCII 12 px，中文 24 px，行高 44 |
| 每列可放行数（32 号） | 564 / 64 = 8 行 |
| 每列可放行数（24 号） | 564 / 44 = 12 行 |

三屏总览：

| 屏 | 控件数 | 布局 | 字号 | 结论 |
|---|---|---|---|---|
| 屏 1 演奏加节奏 | 16 | 2 列 x 8 行 | 32 号 | 宽松 |
| 屏 2 效果器链 | 31（5 个节点面板 + 4 个箭头 + 2 个标注 + 9 个参数控件 + 4 个层 D 控件 + 7 项状态条） | 上半链式图，下半参数与"当前调节"面板 | 32 号（节点名 24 号，状态条 20 号） | 宽松 |
| 屏 3 标定加调试 | 27 | 3 列 | 24 号 | 偏密但可行 |

若屏 3 也要 32 号字，就把 16 轴原始码做成弹出子页，变成 4 屏。本文按 3 屏给方案，并把"16 轴子页"作为可选。

### 2.1 屏 1 演奏加节奏（合并原页 1 与页 3）

坐标表（行 i = 0..7）：

| 行 | y 范围 | 左列控件 x 8..500 | 右列控件 x 516..1016 |
|---|---|---|---|
| 0 | 64..128 | 模式（开关加大字） | BPM（数字加条，大字号） |
| 1 | 128..192 | 滑音 on/off（开关） | BPM 待生效（小色块） |
| 2 | 192..256 | 当前起始音（下拉 3 项） | 鼓机节奏型（下拉 4 项） |
| 3 | 256..320 | 变调（数字加条） | 节拍器 on/off（开关） |
| 4 | 320..384 | 音色（下拉 4 项） | 键盘打鼓 on/off（开关） |
| 5 | 384..448 | 推子档位（色块加文字） | 引导模式 on/off（开关） |
| 6 | 448..512 | looper（4 态色块加文字） | 拍点闪烁（色块） |
| 7 | 512..576 | 复音占用（条加数字） | 小节计数（数字） |

每行内部：标签占 x 起点加 0..150（32 号字，中文最多 4 字 = 128 px），控件占标签右侧到行末。

字段与取值域：

| 字段 | 取值域 | 建议控件 | 更新率 | 优先级 |
|---|---|---|---|---|
| 模式（指板 / 钢琴） | 2 态 | 开关加大字（可点，等价触摸控件 0） | 事件 | 必看 |
| 滑音 on/off | 2 态 | 开关（可点，发 `'W'`） | 事件 | 必看 |
| 当前起始音 | C4 / C5 / C6 | 下拉 3 项（发 `0/24/48`） | 事件 | 必看 |
| 变调 | -12..+12 半音 | 数字加条（中点为零） | 事件 | 必看 |
| 音色 | 0..3（BASS / GUITAR / PIANO / PAD） | 下拉 | 事件 | 必看 |
| 推子档位 | 变调 / 音高颤音 / 音量颤音 / 无 | 色块加文字 | 事件 | 必看（本轮升级：原来标"可选"，因为新增了档 2） |
| looper | 空闲 / 录音 / 回放 / 武装中 | 4 态色块加文字 | 事件 | 必看 |
| 复音占用 | 0..32 | 条加数字 | 10 Hz | 可选 |
| BPM | 40..240 | 数字加条（大字号） | 事件 | 必看 |
| BPM 待生效（等小节线） | 有 / 无 | 小色块（来自 `bpm_pending_obs`） | 1 Hz | 可选 |
| 鼓机节奏型 | 0..3（Rock / 八分摇滚 / 十六分放克 / 圆舞曲） | 下拉 | 事件 | 必看 |
| 节拍器 on/off | 2 态 | 开关（发 `'B'`） | 事件 | 必看 |
| 键盘打鼓 on/off | 2 态 | 开关（发 `'K'`） | 事件 | 必看 |
| 引导模式 on/off | 2 态 | 开关（发 `'U'`） | 事件 | 必看 |
| 拍点闪烁 | 脉冲 | 色块（跟 `bg_beat` 闪） | 实时 | 可选 |
| 小节计数 | 0..65535 | 数字 | 1 Hz | 可选 |

注意：源 B 是"节拍器 / 鼓机"二选一（编译期 `SEL_DRUM`，`top.v:146` 现为 1 等于鼓机）。屏上两个都显示 on 会撒谎。建议用 `led_drum_on` 的算式（`top.v:7054`：`SEL_DRUM==1 && METRONOME_ON && met_on_r`）决定"哪个真的在响"，另一个显示成灰色并标注"已切换为鼓机"。

变调显示口径（必须二选一，不要两个都显示）：建议显示 `transpose_semi`（-12..+12，0 = 不调），这是听觉上的真相，也是 `fader_gear.v:249` 的输出。不要显示 `enc_r`（0..24，12 = 不调），那是内部编码，用户看到 12 会以为升了 12 个半音。

### 2.2 屏 2 效果器链（链式布局，本轮重点）

用户要求体现"效果器链的链"。先把 RTL 里的真实顺序核清楚。

#### 2.2.1 链的真实顺序（从 `rtl/w3c/fx_chain.v` 逐级核实）

| 级 | 模块 | 文件:行号 | 使能来源 | 本级参数 | 输入 |
|---|---|---|---|---|---|
| 1 | 失真 `u_dist` | `fx_chain.v:214-226` | `en_mask_i[0]`（`:180`） | `dist_gain_i`（增益）、`dist_trim_i`（补偿） | `sample_i`（链输入） |
| 2 | 合唱 `u_chorus` | `fx_chain.v:243-262` | `en_mask_i[1]`（`:181`） | `chor_delay_i`（长度）、`dly_mix_i`（干湿，共用） | `d1_sample`（失真输出，`:250`） |
| 3 | 延迟 `u_delay` | `fx_chain.v:277-290` | `en_mask_i[2]`（`:182`） | `dly_delay_i`（长度）、`dly_fb_i`（反馈）、`dly_mix_i`（干湿，共用） | `d2_sample`（合唱输出，`:284`） |
| 4 | 混响 | `fx_chain.v:300-301` | 无（留位直通） | 无 | `d3_sample`（延迟输出） |
| 5 | 音量颤音 `u_trem` | `fx_chain.v:322-334` | 硬接常开 `en_i(1'b1)`（`:330`） | `trem_depth_i`（深度）、`trem_rate_i`（速率） | `d4_sample`（等于 `d3_sample`） |

结论（与用户给的图一致，并有两条 RTL 事实要补）：

```
输入 -> [失真] -> [合唱] -> [延迟] -> [混响(留位直通)] -> [音量颤音] -> 输出
        开/关      开/关      开/关     无参数               常开
        gain       chorlen   dlylen                        depth
        trim                 fb                            rate
                             mix(与合唱共用)
```

> 🔴 **2026-10-17 更新：这张图已过时** —— 屏上**不要画混响节点**，且要在最左**新增「音高颤音」节点**。
> 屏上的显示顺序改为：**音高颤音 → 失真 → 合唱 → 延迟 → 音量颤音**（见 **〇之二 A**）。
> 下面这段"RTL 里的真实顺序"仍然是**音频域的真实链路**（音高颤音不在其中，因为它在振荡器域），两者不矛盾。

补两条 RTL 事实：

1. **混响是留位直通**（`fx_chain.v:300-301`：`d4_valid = d3_valid; d4_sample = d3_sample;`），没有逻辑。链图上画成一个灰色占位节点，让链看起来完整，但不可点、无参数。
2. **合唱与延迟各自独立，串联顺序是合唱在前**（`fx_chain.v:191-197` 原文："延迟与合唱各自独立（用户要求能同时开）；合唱走自己的短延迟线，延迟走自己的长延迟线；两者串联（合唱在前）=> 延迟回声里带着合唱"）。所以链图上合唱必须在延迟左边，顺序不能画反。
3. **mix 是两级共用**：`dly_mix_i` 同时接到 `u_chorus.mix_i`（`:252`）与 `u_delay.mix_i`（`:286`），而顶层只有一个寄存器 `ui_fx_mix`（`top.v:6371`）。所以链图上 mix 画在合唱与延迟之间，标注"两级共用"。
4. **fb 只属于延迟**：`u_chorus.fb_i` 硬接 0（`fx_chain.v:252`，原文理由："合唱线只有约 15 ms 且被 LFO 调制，一旦加反馈，抽头就变成共振梳状滤波器，音色发金属声；真机 chorus 没有反馈"）。所以 fb 只画在延迟节点下。
5. **音量颤音固定常开，没有使能位**（`fx_chain.v:184-189`、`:305-307`：深度为 0 时 `g = 256` => `(x 乘 256) >> 8 = x`，逐位等于输入 => 推子推到零就等于关掉，不需要开关）。所以链图上它的"开/关"栏写"常开"，没有开关控件。
6. **失真没有类型选择**：`dist_sel_i` 在顶层硬接 `2'd0`（`top.v:6369`，注释："没有运行时寄存器，模块里 sel 1/2/3 语义上就等于 0"）。所以屏上不要做"失真类型"下拉。
7. **音量颤音节点的两个参数由推子调**（用户第三轮拍板）：depth 与 rate 在链上保留显示，但点它们不是"选 EC11 目标"，而是"把推子切到档 2"。所以它虽然还在 `fx_chain` 里（链的最后一"大块"），调它的手是推子。见 2.2.3 与 5.4。
8. **三个效果器节点的标题是开关**（用户第四轮拍板）：点 [失真] / [合唱] / [延迟] 的名字就翻转它的开/关，点一下翻一次，不是长按、不是双击、不是进子页。使能来源是 `fx_mask` 的 bit0/bit1/bit2（`fx_chain.v:180-182`）。**音量颤音节点没有开关**（固定常开，见上面第 5 条），所以点它只做"推子切档 2"。见 2.2.2 与 2.2.3。
9. **混响节点的标题不可点**（它没有逻辑，见上面第 1 条）。

#### 2.2.2 屏 2 控件坐标表

布局分四层（全部 1024 宽）：
- 层 A：常驻状态条 y 0..36
- 层 B：链式图 y 44..212（输入/输出标注行 44..72，节点行 76..212）
- 层 C：各节点参数控件 y 220..452（含 mix 共用控件）
- 层 D："当前调节"面板 y 460..596

层 B 节点坐标（节点宽 168，间距 32）：

| 节点 | x 范围 | y 范围 | 控件类型 | 显示内容 | 更新率 | 点它做什么 |
|---|---|---|---|---|---|---|
| 输入标注 | 8..40 | 44..72 | 文本（24 号） | `输入` | 静态 | 无 |
| 失真节点 | 8..176 | 76..212 | 可点面板（含边框） | `失真` 加状态文字 `开` / `关` | 事件 | **翻转失真开关**（屏本地翻位 + `71 10`） |
| 箭头 1 | 176..208 | 132..156 | 文本（24 号） | `->` | 静态 | 无 |
| 合唱节点 | 208..376 | 76..212 | 可点面板 | `合唱` 加 `开` / `关` | 事件 | **翻转合唱开关**（同上） |
| 箭头 2 | 376..408 | 132..156 | 文本（24 号） | `->` | 静态 | 无 |
| 延迟节点 | 408..576 | 76..212 | 可点面板 | `延迟` 加 `开` / `关` | 事件 | **翻转延迟开关**（同上） |
| 箭头 3 | 576..608 | 132..156 | 文本（24 号） | `->` | 静态 | 无 |
| 混响节点 | 608..776 | 76..212 | 只读占位（灰） | `混响` 加 `留位直通` | 静态 | 无（不可点） |
| 箭头 4 | 776..808 | 132..156 | 文本（24 号） | `->` | 静态 | 无 |
| 音量颤音节点 | 808..976 | 76..212 | 可点面板 | `音量颤音` 加 `常开` 加 `推子控制` | 事件 | 推子切到档 2（**下一轮可选增强**，见 2.2.5），**不翻转**（它没有开关） |
| 输出标注 | 984..1016 | 44..72 | 文本（24 号） | `输出` | 静态 | 无 |

节点面板内部（每节点 168 宽，136 高）：
- 名称行 y 节点顶加 8..48（32 号字，2 个中文 = 64 px，居中）， **这一行就是"开关按钮"**，点它翻转
- 状态行 y 节点顶加 56..96（24 号字）， **同时有文字与底色**：失真/合唱/延迟显示 `开` 或 `关`；混响显示 `留位直通`；音量颤音显示 `常开`
- 参数名清单 y 节点顶加 100..128（20 号字，如 `gain trim`）

为什么状态要"文字加底色"两样都给：底色（亮 = 开、灰 = 关）解决"一眼看到"，文字解决"底色相近或强光下也能读准"。两条信息都从回读的 `ui_fx_mask` 来，不会不一致。

层 C 参数控件坐标（每控件高 56，32 号字，含参数名与数值；控件本身可点）：

| 控件 | x 范围 | y 范围 | 显示内容 | 更新率 | 可点 |
|---|---|---|---|---|---|
| 失真 增益 `gain` | 8..176 | 220..276 | `gain` 加 `4.0x` | 事件 | 是（EC11 目标 0） |
| 失真 补偿 `trim` | 8..176 | 280..336 | `trim` 加 `0.25` | 事件 | 是（EC11 目标 1） |
| 合唱 长度 `chorlen` | 208..376 | 220..276 | `chorlen` 加 `15ms` | 事件 | 是（EC11 目标 2） |
| mix 共用 | 208..576 | 344..400 | `mix` 加 `0.50` 加 `合唱/延迟共用` | 事件 | 是（EC11 目标 5） |
| 延迟 长度 `dlylen` | 408..576 | 220..276 | `dlylen` 加 `168ms` | 事件 | 是（EC11 目标 3） |
| 延迟 反馈 `fb` | 408..576 | 280..336 | `fb` 加 `0.38` | 事件 | 是（EC11 目标 4） |
| 音量颤音 深度 `depth` | 808..976 | 220..276 | `depth` 加 `0.00` | 事件 | 否（只读；推子接管属下一轮，见 2.2.5） |
| 音量颤音 速率 `rate` | 808..976 | 280..336 | `rate` 加 `7` | 事件 | 否（同上） |

层 C 一共 **8 个控件**。第三轮曾在 8..176 / 340..396、208..376 / 280..336、408..576 / 344..400 各放一个独立的"使能开关"控件，本轮**取消**：翻转开关改成点**节点标题**（层 B 的名称行），不再单独占控件。腾出的三块位置留空，或放一行小字提示（例如 `点标题开关`）。

**参数本身怎么调（最小可用第一步就能用，零 FPGA 改动）**：

| 手段 | 怎么落地 | 需要动 rtl 吗 |
|---|---|---|
| 屏上直接改参数（滑条 / 数字输入 / 加减按钮） | 用**现有的** `71 11..18 <值> FF FF FF` 帧（`uart_ui.v:428-483`，早已实现） | **不需要**。所以即使 EC11 目标选择还没做，屏 2 的参数**已经能改** |
| 用 EC11 手拧 | 需要"屏选目标" + `uart_ui` 加输入端口 | 需要，属**下一轮可选增强**（见 2.2.5） |
| 开关开/关 | 屏本地翻位 + **现有的** `71 10 <掩码>` 帧 | **不需要** |

层 D 面板（"当前调节"）：

| 控件 | x 范围 | y 范围 | 控件类型 | 显示内容 | 更新率 |
|---|---|---|---|---|---|
| 当前调节标题 | 8..1016 | 460..508 | 文本（32 号） | `正在调：失真 增益` | 事件 |
| 当前值数字 | 8..300 | 516..568 | 数字（32 号） | `4.0x` | 事件 |
| 当前值条 | 308..1016 | 516..568 | 进度条（全宽） | 0..100% | 事件 |
| 操作提示 | 8..1016 | 576..596 | 文本（20 号） | `点节点名开关效果器；点参数名选中它` | 静态 |

高亮规则（两类必须能同时显示且不混淆）：

| 高亮种类 | 用在哪里 | 建议视觉表现 | 含义 |
|---|---|---|---|
| **开关状态高亮** | 三个效果器节点的**名称行**（层 B） | 名称行**整行亮底** + 状态行文字 `开`；关时名称行**灰底** + 状态行文字 `关` | 亮 = 该效果器**开启**，灰 = **关闭**。这是"状态"，不是"选中" |
| **EC11 目标高亮** | 被选中的那个**参数控件**（层 C） | 参数控件**加粗边框**（用矩形控件当框）+ 数值变色 `FFFF00` | 亮边框 = **这个参数被选中**。这是"选中"，不是"状态" |
| 推子接管高亮（下一轮，见 2.2.5） | 音量颤音节点名称行与它的 depth / rate | 橙底 `FF8000` + 双线边框 + 文字 `推子控制` | 这两个参数**由推子连续控制** |
| 无高亮 | 其余节点与控件 | 暗底 + 细边框 | 常态 |

为什么"开关状态"用**整行亮底**、而"选中"用**加粗边框**：两种语义不同（一个是"这个块开不开"，一个是"我在调哪个数"），视觉通道也要不同。若都用"亮底"，用户会分不清"这个效果器开着"和"我在调这个效果器的参数"，而这两件事可以同时成立。

补充三条：

- 两类高亮**可以同时出现**（选中了失真增益，同时合唱是关的）。这是"状态"与"选中"两件事的可见形式，不是冲突。
- 开关状态**必须同时有文字**（`开` / `关`），不能只靠颜色：颜色在强光/色弱下不可靠，而且 `开` 这个字本身还兼作"点了会变关"的提示。
- 高亮分两级：点下去**本地立即高亮**（零延迟），随后由 FPGA 的**回读确认**（读回 `ui_fx_mask`）成为权威状态。第二级对"开关状态"尤其必要，理由见 6.5。

#### 2.2.3 两种点击目标（本轮的核心交互）

| 点哪里 | 做什么 | 高亮含义 |
|---|---|---|
| **点节点标题**（失真 / 合唱 / 延迟 的名字，层 B 的名称行） | **翻转该效果器的开/关**：屏本地把掩码缓存的对应位翻转，再用**现有的** `71 10 <新掩码> FF FF FF` 整帧写出。点一下翻一次（不是长按、不是双击、不是进子页） | **亮 = 开启，灰 = 关闭**（同时有文字 `开` / `关`） |
| **点节点下方的参数控件**（gain / trim / chorlen / dlylen / fb / mix，层 C） | **选中该参数**（设 EC11 目标）。需要动 rtl，属**下一轮可选增强**（见 2.2.5）；但**参数本身的最小可用路径不受影响**：屏可以直接用现有 `71 11..18` 帧改数值 | **亮边框 = 该参数被选中** |
| 点音量颤音节点标题或它的 depth / rate | 推子切到档 2（**下一轮可选增强**，见 2.2.5）。**它不翻转任何开关**（音量颤音固定常开） | 橙 = 推子在调 |
| 点混响节点标题 | 什么都不发（不可点） | 无（留位直通，无逻辑） |

设计约定：

1. **翻转就是"点一下翻一次"**：不是长按、不是双击、不是进子页。TJC 的触摸事件本身是"按下即发一次 `0x65`"，屏侧在收到触摸回调时翻转本地缓存并发一帧即可。
2. **音量颤音节点没有开关**（它固定常开，`fx_chain.v:330` 硬接 `en_i(1'b1)`），所以点它只做"推子切档 2"，不翻转。
3. **两类点击目标各自独立**，不会"点错东西"：名称行 = 开关，参数控件 = 选中。混响节点标题不可点。
4. **点参数控件时推子档不动**（推子与 EC11 是两条独立通路，各自保持自己的目标）。这一条只在下轮增强落地后才有实际影响，届时若要改成"自动切回档 0/1"，再单独确认。

#### 2.2.4 点击时发什么帧（原则：不新增协议）

| 交互 | 屏发出的帧 | FPGA 侧落地 | 需要动 rtl 吗 |
|---|---|---|---|
| **开关翻转**（点节点标题） | `71 10 <新掩码> FF FF FF` | `fx_mask_o <= val_q`（**早已实现**，`uart_ui.v:428-430`） | **不需要** |
| **参数改值**（滑条 / 数字 / 加减按钮） | `71 11..18 <值> FF FF FF` | `fx_*_o`（**早已实现**，`uart_ui.v:431-483`） | **不需要** |
| 选中参数（供 EC11 手拧） | `65 03..08 FF FF FF` | `enc_tgt_r` | 需要，**下一轮可选增强** |
| 推子切档 2 | `65 09 FF FF FF` | `gear_sel2_i` | 需要，**下一轮可选增强** |
| 推子档循环 | `65 13 FF FF FF` | `gear_next_o` | 需要，**下一轮可选增强** |
| 退出选中 | `65 14 FF FF FF` | `enc_obj_r` 回 0 | 需要，**下一轮可选增强** |

**本轮只做前两行**（零 rtl 改动）。后四行是设计留档，落地见 2.2.5。

开关翻转的具体流程（屏侧三步，不需要 FPGA 配合）：

```
1. 屏收到触摸回调（TJC 的 0x65）
2. 屏本地掩码缓存  mask_local <= mask_local ^ 对应位
3. 屏发 71 10 <mask_local> FF FF FF
4. 屏按新的 mask_local 重绘该节点（亮底/灰底 + 文字 开/关）
```

#### 2.2.5 下一轮可选增强（需要动 rtl，不塞进最小可用第一步）

| 增强 | 要动什么 | 为什么不在第一步 |
|---|---|---|
| EC11 选中参数（`65 03..08`） | `uart_ui` 加 `enc_up_i` / `enc_dn_i` / `enc_tgt_o`；加 8 个影子字节寄存器；`enc_obj_r` 扩到 2 位 | 要改两个 RTL 模块 + 重跑 `tb_uart_ui`。而**参数本身用现有 `71 11..18` 帧已经能改**，不阻塞屏 2 上线 |
| 推子切档 2（`65 09`） | `uart_ui` 加 `gear_to_trem_o`；`fader_gear` 加 `gear_sel2_i` 与三态切档；`top.v` 加 mux | 要改三个 RTL 模块 + 改 `tb_fader_gear` 的 6 处判据 + 一次 PnR |
| 推子档循环 / 退出选中（`65 13` / `65 14`） | `uart_ui` 加两个单周期脉冲输出 | 与上面两条同批做更省 |
| 掩码"原子翻转"（FPGA 侧异或） | `uart_ui` 加 3 个异或分支 | **本轮不做**（用户澄清"不一定要实现翻转，状态翻转就行"）。现有做法在单人使用时够用，风险见 6.5 |

"推子切到档 2"落地时的做法（设计留档，本轮不动）：`uart_ui` 出一个单周期脉冲 `gear_to_trem_o`，顶层 OR 进 `fader_gear` 的新输入 `gear_sel2_i`，由它把 `gear_o` **直接写成 `2'd2`**（与当前档位无关）。不用"连发若干次 `'J'` 让它循环过去"：那样落点取决于当前档位，且"回读 -> 算次数 -> 发脉冲"之间档位可能被串口或矩阵键改掉，有竞态。

### 2.3 屏 3 标定加调试（合并原页 4 与页 5）

坐标表（3 列，24 号字，行高 44）：

| 列 | x 范围 | 行数 | y 范围 | 内容 |
|---|---|---|---|---|
| 列 1 标定 | 4..340 | 8 | 40 加 i 乘 44（i=0..7）到 392 | 标定状态与两个按钮 |
| 列 2 调试 | 344..680 | 12 | 40 加 i 乘 44（i=0..11）到 568 | 故障与溢出分源 |
| 列 3 上 计数与显示 | 684..1020 | 7 | 40 加 i 乘 44（i=0..6）到 348 | 计数器与 Test Mode |
| 列 3 下 16 轴原始码 | 684..1020 | 4 x 4 网格 | 356..572（每格 84 x 54） | `af0_pol` 16 轴 |

列 1 标定（8 行）：

| 字段 | 取值域 | 建议控件 | 更新率 | 优先级 |
|---|---|---|---|---|
| 自动零点完成 `at_done` | 有 / 无 | 色块 | 1 Hz | 必看 |
| 被跳过的轴 `at_skip` | 8 位位图 | 8 个色块（压成一行） | 1 Hz | 必看 |
| 标定失败 `at_fail` | 有 / 无 | 色块 | 1 Hz | 必看 |
| `span` 状态机 | 0..7（IDLE / PROMPT / SETTLE / VOTE / FIRE / WAITBUSY / NEXT / DONE） | 数字加文字 | 2 Hz | 必看 |
| 当前轴 `sp_cur_axis` | 0..15 | 数字 | 2 Hz | 必看 |
| 拒绝计数 | 0..8 | 数字 | 2 Hz | 必看 |
| 拒绝原因 | 6 种（`!` / `o` / `w` / `b` / `?` / `0` / `1` / `2`） | 文字 | 事件 | 必看 |
| `tare` / `span` 按钮 | 无 | 两个按钮（发 `'T'` / `'S'`） | 无 | 必看 |

列 2 调试（12 行）：

| 字段 | 取值域 | 建议控件 | 更新率 | 优先级 |
|---|---|---|---|---|
| 故障总标志 | 有 / 无 | 色块（`fault_sticky`） | 1 Hz | 必看 |
| ADC SPI 故障 | 每片 1 位 | 3 个色块（`af_fault`） | 1 Hz | 必看 |
| mixer 超时 | 有 / 无 | 色块（`mx_fault`） | 1 Hz | 必看 |
| 溢出总标志 | 有 / 无 | 色块（`ovf_any`） | 1 Hz | 必看 |
| 溢出分源 1..8 | 每源 1 位 | 8 行文字（`ee_ovf` / `ee_lost` / `sa_overflow` / `looper_overflow` / `mg_overflow` / `txf_ovf` / `eb_ovf` / `eb_drop`） | 1 Hz | 必看 |

列 3 上（7 行）：

| 字段 | 取值域 | 建议控件 | 更新率 | 优先级 |
|---|---|---|---|---|
| 屏帧计数 | 0..65535 | 数字（`ui_frame_cnt`） | 1 Hz | 必看 |
| 屏归位次数 | 0..65535 | 数字（`ui_resync_cnt`） | 1 Hz | 必看 |
| 屏错帧次数 | 0..65535 | 数字（`ui_err_cnt`） | 1 Hz | 必看 |
| 屏握手 | 有 / 无 | 色块（`ui_hb_ready`） | 1 Hz | 必看 |
| Test Mode 状态 | 关 / 4 / 8 / 16 / 32 | 数字加文字 | 事件 | 必看 |
| 显示模式 | 波形 / 李萨如 / FFT | 下拉 | 事件 | 可选 |
| 推子档位 | 变调 / 音高颤音 / 音量颤音 / 无 | 色块加文字 | 事件 | 可选 |

列 3 下：16 轴原始码 `af0_pol`（0..4095），4x4 网格，每格数字，更新率 2 Hz，优先级必看。

这一页是省最多事的一页。现状 `'P'` / `'N'` 回的是 8 字节 ASCII 行（`pos_probe.v:25-31`），而且 `'P'` 的通道号是"此刻正在被 ADC 扫描的那个"，逐帧轮转，连发 10 次会拿到 10 个不同通道（`pos_probe.v:40-44`），人眼根本没法用它研究某一个轴。屏能把 16 轴一次性摆成表，这是屏相对串口助手的最大增量价值。

若嫌列 3 挤，把 16 轴原始码做成弹出子页（点一个按钮展开），就变成 4 屏。

### 2.4 手拧 / 开关 / 下拉 分类

| 类型 | 字段 | 理由 |
|---|---|---|
| 手拧（连续或多档） | BPM、变调、`gain`、`trim`、`mix`、`fb`、`dlylen`、`chorlen`、音量颤音深度、音量颤音速率 | 值域宽，需要边转边听，相对步进最自然 |
| 开关（双态） | 模式、滑音、节拍器、键盘打鼓、引导、失真/合唱/延迟使能 | 只有两态，拧旋钮是浪费 |
| 下拉（少量枚举） | 音色 4 项、起始音 3 项、鼓机节奏型 4 项、显示模式 3 项 | 精确选择，屏点选比拧快（与 `产品形态决议清单.md:65` "精确量走串口屏"一致） |
| 只读 | 复音占用、标定状态、故障、计数器、音量颤音深度与速率（档 2 时由推子控制） | 不是设定值，是观测量 |

### 2.5 常驻状态条（替代原"总览页"）

每屏顶部 y 0..36 放一条常驻状态条，内容固定 **7 项**（本轮从 6 项加到 7 项，新增"推子档"），每项约 146 px 宽，字号 20 号（ASCII 10 px，中文 20 px）：

`模式 | BPM | 变调 | 音色 | 推子档 | 效果链 | 故障`

第 5 项"推子档"显示**档位名字**，不是数字（用户第三轮要求能看出推子现在管什么）：

| `led_gear_st` | 状态条显示 | 颜色 |
|---|---|---|
| 2'd0 | `变调` | 紫 `C_VIOLET`（与灯 3 一致，`led_indicator.v:225`） |
| 2'd1 | `音高颤音` | 青 `C_CYAN`（`:226`） |
| 2'd2 | `音量颤音` | 黄 `C_YELLOW`（`:227`） |
| 2'd3 | `无` | 灭 `C_OFF`（`:228`） |

推子档这一项**同时是控件**（可点，发 `65 13` = 档位循环），所以用户在屏上任何一页都能切档并立刻看到名字变化。

这样在任何屏都能看到关键状态，不必来回切页，也不必单独占一屏。效果链显示成 3 个小色块（失真/合唱/延迟）加简短文字，例如 `DIST+DLY`。故障项直接用 `fault_sticky` 的颜色。

屏 1 的"推子档位"那一格（第 5 行左列）与状态条第 5 项是**同一个信息的两个位置**：状态条是全局常驻，屏 1 那一格可以做得更大、带上"当前推子管哪两个推子"的小字说明（例如 `CH2=深度 CH3=速率`）。两处都从 `led_gear_st` 回读，不会不一致。

---

## 三、接线：屏直连 `D14` / `D15`

### 3.1 现状（已核）

| 项 | 事实 | 出处 |
|---|---|---|
| 物理口 | `D14`（RX）/ `D15`（TX），走 `XH_SCREEN` | `top.v:488-489` |
| 该口承载 | 调试加命令加串口屏共用一条 | `top.v:1109` 明写 |
| 屏到 FPGA | 活的。`uart_ui` 解析 TJC 返回帧 | `uart_ui.v:336-517` |
| FPGA 到屏 | 不通。`tx_busy_i` 接死 | `top.v:1217` |
| ESP32 独立口 | `G22`（RX）/ `G21`（TX），走 `XH_ESP32` | `top.v:523-524` |
| 该口承载 | 曲谱接收（`evt_uart_rx`）加上行事件帧（`evt_upstream`） | `top.v:1565`、`:5807` |
| 回包镜像 | 命令回包同时喂 `u_uart_tx`（板载 `D15`）和 `u_uart_tx_esp`（`G21`） | `top.v:1955-1962` |

按用户拍板，屏走 `D14`/`D15` 直连 FPGA。原方案里"屏挂 ESP32 的 `GPIO4`/`GPIO5`"这条支路删除，不再考虑。

### 3.2 必须做的三件事

**第一件：FPGA 到屏的发送通路（这是最大的一块）**

必须澄清一个事实：`uart_ui` 内部**根本没有发送状态机**。`tx_start_o` / `tx_data_o` 在全模块只出现三处，都是"清零"：

```
rtl/w3c/uart_ui.v:317-318   （复位分支）tx_start_o <= 1'b0; tx_data_o <= 8'd0;
rtl/w3c/uart_ui.v:326       （每拍默认）tx_start_o <= 1'b0;
```

所以 `top.v:1217` 的 `tx_busy_i = 1'b1` 不是"把一个能用的发送器关掉"，而是"把一个**从未被驱动**的口标成永久忙"。要"接活 TX"实际是**新写一个发送器**，不是把现成的接上。这一点直接影响工作量估算。

两条实现路线：

| 路线 | 做法 | 优点 | 缺点 |
|---|---|---|---|
| A（推荐） | 在 `uart_ui` 内新写回读发送器：一个文本拼装 FSM，把 `tx_start_o` / `tx_data_o` 接进 `u_tx_fifo` 的 `push_i` / `data_i`，`tx_busy_i` 接 `~txf_ready` | 6 个效果器参数寄存器加 EC11 目标寄存器已经在模块内，回读它们零引线 | `uart_ui` 变大；其余 21 条状态要新增输入端口 |
| B | 新增独立模块 「rtl/w3c/hmi_status.v」（历史计划路径，当前未提供），照 `pos_probe.v` 的成熟结构（文本拼装加 ready 握手加 `QUEUE_WHEN_BLOCKED`），保持 `uart_ui` 只收不发 | 对 `uart_ui` 的接收 FSM 零风险 | 6 个参数寄存器要引出（或让 `hmi_status` 只读 `ui_fx_*` 的顶层线，反正已经在顶层） |

无论走哪条，**多字节文本必须一次独占 TX 通路**，不能与命令回执交错。理由是 `uart_tx_fifo.v:116-129` 记录的那条教训：上游若只看 `ready_o`（队列没满）就开新包，两个包会在 FIFO 里首尾相接，接收端按行读就错位（实测症状 `0\n\nP217`）。现有先例是 `rec_dump` 的导出通路，`top.v:3752-3758` 的注释写着"Export bypasses this FIFO and owns both UARTs until its footer ends. Normal replies queue here; ready-aware producers pause during export."，建议照它做。

另外，回读通路的时钟必须用慢使能（例如 1 kHz），不要进 50 MHz 关键路径，理由见第九节。

**第二件：新增回读帧**，见第六节。

**第三件：波特率对齐**，见 3.3。

### 3.3 波特率：屏侧要配多少

先说清楚一个容易混的点：`uart_ui` 的 `BAUD` 参数**不决定实际波特率**。它只用来算空闲归位阈值（`uart_ui.v:197-199`：`BYTE_CLK_I = (CLK_HZ + BAUD/2)/BAUD`）。实际波特率由 `uart_rx.BAUD_DIV` 和 `uart_tx.BAUD_DIV` 决定（`BAUD_DIV = 50 MHz / 波特率`）。

现值的两处不一致（都是事实，不矛盾）：

| 位置 | 值 | 说明 |
|---|---|---|
| `uart_ui.v:61` 模块默认 | `BAUD = 1000000` | 只有 `tb/w3c/tb_uart_ui.sv` 用它 |
| `top.v:1188` 交付实传 | `.BAUD(500_000)` | 与 `uart_rx.BAUD_DIV=100` 同档 |
| `uart_rx`（`top.v:1095`） | `.BAUD_DIV(100)` | 500 kbaud，50 MHz / 500 k 等于 100，整除，零误差 |
| `uart_tx`（`top.v:1924`） | `.BAUD_DIV(100)` | 同上 |

所以**上板实际跑的是 500 kbaud 8N1**，屏侧必须配 500000。

可选档位（来自 `uart_rx.v:28-34` 的表）：

| 波特率 | BAUD_DIV | 50 MHz / 波特率 | 误差 | 备注 |
|---|---|---|---|---|
| 1 M | 50 | 50.000 | 0%（整除） | 交付默认曾是它，但 2026-09-24 实测本板有误码，已降档 |
| 500 k | 100 | 100.000 | 0%（整除） | 现值。2026-09-24 起交付档 |
| 460800 | 108 | 108.51 | 0.47% | 标准档，对端兼容性好 |
| 230400 | 217 | 217.01 | 0.005% | 备选 |
| 115200 | 434 | 434.028 | 0.006% | 历史档位 |

**未确认项（必须查屏手册）**：淘晶驰 TJC 的 `bauds` 属性是否支持 500000。这个值**不是标准波特率**。已知事实：ESP32 侧那块 T1 屏（`TJC3224T120_011R_A01`）的工程 `program.s` 里写的是 `bauds=115200`（`esp32/串口屏上位机使用说明.md:281`、`esp32/串口屏指令表.md:95`）。而 `files/00-总览/对外问询清单.md:76-78` 的 Q7（"串口屏最高可设 baud 是多少"）**至今未问、未答**。

三种处理：

1. 若屏支持 500000：什么都不用改，屏工程里把 `bauds` 设成 500000。
2. 若屏不支持 500000 但支持 460800：FPGA 侧改 4 处（见下），误差 0.47% 可接受。
3. 若屏只支持到 115200：FPGA 侧同样改 4 处，误差 0.006%，最稳。代价是回读 30 条状态约 600 字节需要 52 ms，对参数面板完全够用（现状的 `'P'` 诊断包本来也是人眼读的）。

**改波特率要动的地方（注意：`top.v:1061-1067` 那条"四处一起改"的注释已经过时）**：

板载口这一侧要改 4 处：

```
rtl/top.v:1095   uart_rx     .BAUD_DIV(100)   -> 434（若 115200）
rtl/top.v:1188   uart_ui     .BAUD(500_000)   -> 115200
rtl/top.v:1333   calib_cmd   .BAUD(500_000)   -> 115200
rtl/top.v:1924   uart_tx     .BAUD_DIV(100)   -> 434
```

**不要**跟着改的 3 处（它们在 ESP32 那条线上，仍走 500 k）：

```
rtl/top.v:1144   uart_rx_esp  .BAUD_DIV(100)
rtl/top.v:1558   evt_uart_rx  .BAUD(500_000)   <- 它已改接 esp_rx_done（:1565）
rtl/top.v:1956   uart_tx_esp  .BAUD_DIV(100)
```

`top.v:1061-1067` 的注释把 `evt_uart_rx` 列在"板载四处"里，那是它还在板载口时的写法。2026-10-11 它改走 ESP32 独立 UART 之后，这条注释就与代码不符了。改波特率时按上面的清单走，不要按那条注释走。

### 3.4 与调试串口的冲突（讲清加方案）

**冲突是硬件事实**：`files/10-硬件/Console拓展板接线需求-20261003.md:563` 明写"串口屏 | 共用同一条 UART | 已分配；与调试口不能同时用"。屏长期插在 `D14`/`D15` 上，PC 的 USB-TTL 就没地方插了。

但要把"看"和"发"分开看，因为这两件事的现状不同：

| 方向 | 现状 | 屏占用板载口之后 |
|---|---|---|
| FPGA 到 PC（看回包、看诊断） | 回包同时镜像到板载 `D15` 和 ESP32 的 `G21`（`top.v:1955-1962`） | **仍然可用**，走 `G21` 到 ESP32 再到 BLE 到 PC。ESP32 侧的反向通路已验收（`esp32/README.md` 记"2000 字节 round-trip 逐字节一致"） |
| PC 到 FPGA（发命令 `'T'`/`'S'`/`'W'` 等） | `calib_cmd` 只吃板载口的 `ur_done`（`top.v:1338`） | **断了**，这是真正的损失 |

所以真正要解决的只是"命令输入改走哪条路"。三个方案：

| 方案 | 做法 | 评价 |
|---|---|---|
| 1（推荐） | 把 `calib_cmd.rx_done_i` / `rx_data_i` 从 `ur_done` / `ur_data` 改成 `esp_rx_done` / `esp_rx_data`（即改走 `G22`），板载口完整让给屏 | **物理隔离，零风险**。理由见下 |
| 2 | 屏上做一页"命令"页，用 TJC 的 `printh` 发裸字节（例如 `printh 54` 发 `'T'`） | 可用，但要在屏工程里为每条命令做一个按钮，工作量落在屏侧；且 `uart_ui` 会把这些字节当"非法返回码"计入 `err_cnt_o`（不影响功能，只是计数器会涨） |
| 3 | 物理切换：调试时拔屏插 USB-TTL | 零 RTL 改动，但台面操作麻烦，且不能边看屏边调 |

方案 1 为什么零风险：`calib_cmd` 自带 `0xA5` 帧边界跟踪。`top.v:1516-1522` 已核实：`calib_cmd` 的 `idx_q` 只在看到 `0xA5` 时离开 0，而命令只在 `idx_q == 0` 时被识别，所以"帧内的 `T`/`S`/`X`/`M` 是载荷，不当命令"（`top.v:1258` 原文）。ESP32 那条线上跑的是 0xA5 开头的曲谱帧，所以命令与曲谱帧可以安全共线。而屏帧（TJC 的 `0x65` / `0x71`）走板载口，与 `calib_cmd` **物理上不同线**，不可能互相误判。这比原来"屏与命令共用一条线"的局面更干净。

代价：需要 ESP32 侧把 PC 的字节透传过来。它的定位本来就是"无线的 USB 线，PC 怎么发就原样照搬、不看内容"（`top.v:1127`），反向通路也已验收，所以这一侧基本不用改。

---

## 四、EC11 映射方案（屏点选激活，EC11 手拧）

**本节定位**：这是"**下一轮可选增强**"的设计（见 2.2.5）。它需要动 rtl（`uart_ui` 加输入端口、`enc_obj_r` 扩位），所以**不塞进最小可用第一步**（第八节）。但**参数本身的最小可用路径不受影响**：屏可以直接用现有 `71 11..18` 帧改数值（见 2.2.2）。

### 4.1 EC11 现在干什么（已核，已接线可用）

```
物理：enc_a_i(E19) / enc_b_i(C19) / enc_sw_i(C18)      top.v:513-515
  -> Z-safe 归一（用 === 1'b0 判）                       top.v:719-721
  -> sync_input 打两拍（K-62 纪律：先同步再去抖）         top.v:723-728
  -> debounce（NKEY=1, DB_MS=5, ACTIVE_LOW=1）           top.v:731-755
  -> enc_cw_w / enc_ccw_w / enc_sw_down_w
  -> 除 4（一次"定位" = 4 个格雷步）                      top.v:778-785
  -> enc_step_cw_w / enc_step_ccw_w
  -> 按 enc_obj_r 分流                                   top.v:793-796
       enc_obj_r = 0（BPM）   -> enc_bpm_up_w/dn_w    -> play_seq.bpm_up_i/bpm_dn_i（加减 1 BPM）
       enc_obj_r = 1（变调）  -> enc_trans_up_w/dn_w  -> cmd_trans_up_req（加减 1 半音）
  -> 对象切换 = 按压                                     top.v:758-762
       enc_sw_down_w => enc_obj_r <= ~enc_obj_r
```

| 问题 | 答案 |
|---|---|
| 现在有几个对象 | 2 个：0 = BPM，1 = 变调（`enc_obj_r` 是 1 位） |
| 怎么换对象 | 按压一下（`enc_sw_down_w` 翻转 `enc_obj_r`） |
| 一格等于多少 | 除 4 之后等于 1 步（`top.v:771-785`），即 BPM 加减 1 或变调加减 1 半音 |
| 变调那条走哪 | 与串口 `'F'` / `'G'` 同一条下游（`cmd_trans_up_req`，`top.v:1324`），复用现成通路 |
| BPM 那条走哪 | 直接进 `play_seq.bpm_up_i` / `bpm_dn_i`（`top.v:2537-2538`），不过小节对齐器（`:791-792` 有意为之：旋钮要边转边听） |
| 指示 | 灯 5：动过就临时显示对象色（黄 = BPM，紫 = 音高），1 秒回落（`led_indicator.v:58-68`） |

### 4.2 用户要的方案

```
屏点选  = 设定 EC11 目标（屏发一条命令"EC11 目标 = 第 N 个参数"）
EC11 转 = 只增减当前目标那一个参数
EC11 按 = 保持"切换对象"语义（见 4.6）
```

优势：`enc_obj_r` 不必扩到 11 个对象，只要"屏指定的那一个"。这也符合用户第 4 条"点击对应效果器的控件就可以激活 EC11 对该参数的调节"。

**EC11 目标清单 = 6 个（失真 / 合唱 / 延迟 的程度参数）**：

| 目标号 | 参数 | 所属节点 | 顶层线 | 步进量 | 饱和上限 |
|---|---|---|---|---|---|
| 0 | 失真 增益 `gain` | 失真 | `ui_fx_gain`（16 位） | 加/减 16'h0100 | 0 .. 16'hFE00（字节 254） |
| 1 | 失真 补偿 `trim` | 失真 | `ui_fx_trim`（16 位） | 加/减 16'h0100 | 0 .. 16'hFE00 |
| 2 | 合唱 长度 `chorlen` | 合唱 | `ui_fx_chorlen`（11 位） | 加/减 11'd32 | 0 .. 2016（字节 63） |
| 3 | 延迟 长度 `dlylen` | 延迟 | `ui_fx_dlylen`（14 位） | 加/减 14'd128 | 0 .. 16256（字节 127） |
| 4 | 延迟 反馈 `fb` | 延迟 | `ui_fx_fb` | 加/减 1 | 0 .. 254 |
| 5 | 干湿混合 `mix` | 合唱与延迟共用 | `ui_fx_mix` | 加/减 1 | 0 .. 254 |

**音量颤音的 depth 与 rate 不在 EC11 目标里**（改由推子档 2 负责）。这是**已定**（用户第三轮拍板：点音量颤音节点时推子自动切到该档），理由与交互见 2.2.3 与 5.4。

`mask`（3 个使能开关）也不进 EC11 目标，它是开关，屏上直接点。

### 4.3 屏点选怎么实现（复用现有 `0x65` 触摸帧，不新增帧类型）

`uart_ui.v:369-388` 已经处理 `RET_TOUCH`（`0x65`）帧，按 `body_q`（控件 ID）分派：`body_q == 0` 翻转模式，`body_q == 2` 切 Test Mode 档。

所以在同一个 `case` 里加分支即可，映射表见 2.2.4（控件 ID 3..8 对应 EC11 目标 0..5，9 = 推子切档 2，13 = 推子档循环，14 = 退出 EC11 参数模式；开关翻转走 `71 10`，不占控件 ID）。

屏侧只需把屏 2 的那些控件设成对应 ID，点一下屏就发 `65 <ID> FF FF FF`。**不需要新帧类型、不需要新返回码**。

同时屏上做两级反馈：
1. 本地立即高亮（零延迟，点哪亮哪）。
2. FPGA 回读确认（读回 `enc_tgt_o` 与 `enc_obj_r`，见第六节），把高亮改成权威状态。

第 2 级是必要的，因为 `esp32/evidence/串口屏HMI验收报告-20261001.md` 第三节记录过一个坑：**"值对了但屏不重绘"**（实测 `get t3.txt` 回 `pBT OK` 而屏上仍是 `BT --`），以及"屏上没变不等于命令没生效"。只靠本地高亮会在帧丢失时显示错误状态。

### 4.4 `uart_ui` 具体要加什么（这是本节的关键约束）

**结构性约束**：8 个（加 mask 共 9 个）效果器参数寄存器是 `uart_ui` 内部的 `output reg`（`uart_ui.v:165-173`），唯一写入点在帧解析那条 `else if (body_q == 8'd16..24)` 链（`:428-483`）。顶层只能读 `output`，不能反向赋值。所以 EC11 要写它们，**必须给 `uart_ui` 新增输入端口**。

建议新增 3 个端口：

```verilog
input  wire       enc_up_i,    // EC11 顺时针一步（单周期脉冲）
input  wire       enc_dn_i,    // EC11 逆时针一步（单周期脉冲）
output reg [2:0]  enc_tgt_o    // 当前 EC11 目标（0..5），同时供屏回读
```

内部加一个 `reg [2:0] enc_tgt_r`，由 4.3 的触摸帧设置，`enc_tgt_o` 就是它的观测输出。

**步进逻辑写在哪儿**：写在**现有那条 `else if (body_q == ...)` 链之外、同一优先级层级**，用一个 `if / else if` 链表达"帧写优先、EC11 次之"：

```
if (帧路径命中某参数)      该参数 <= 帧值
else if (enc_up_i)         按 enc_tgt_r 选中的那一个 <= 步进加
else if (enc_dn_i)         按 enc_tgt_r 选中的那一个 <= 步进减
```

注意：**必须复用同一组换算函数**。`uart_ui` 的 9 条换算各不相同（`gain` / `trim` 乘 256，`dlylen` 乘 128，`chorlen` 乘 32，`dlylen` / `chorlen` 还有饱和），EC11 那一路不能另写一套，否则"屏发 23"和"EC11 拧到 23"会得到不同的值，这是最容易埋的坑。

**最稳的落地方式（推荐）**：为每个参数加一个 **8 位影子字节寄存器**（`fx_gain_b` / `fx_trim_b` / ... / `fx_chorlen_b`），帧路径与 EC11 路径**都只写影子字节**（0..254 的整数），再由**同一处**换算从影子字节产生 `fx_*_o`。好处三条：

1. 格点天然对齐（影子是整数 0..254），不会出现"从 16383 减 128 得到 16255"这种不在格点上的值。
2. 饱和语义只在一处（换算函数里），与帧路径逐位一致。
3. EC11 的步进就是"影子字节加 1 或减 1"，与目标号无关，代码极简。

代价：8 个影子寄存器共 64 个 FF。**注意时序**：换算必须保持"帧落地后 1 拍更新 `fx_*_o`"的既有延迟，所以要用组合的 next 值参与换算（`fx_gain_o <= {next_gain_b, 8'b0}`），不要写成"先写影子、下一拍再换算"，否则 `fx_*_o` 会晚 1 拍，可能踩到 `tb/w3c/tb_uart_ui.sv` 的既有判据。这一条必须在动手时核对那个 tb。

### 4.5 脱屏可用性（回答"屏没接时 EC11 干什么"）

方案设计成**两态兼容**，`enc_obj_r` 从 1 位扩到 2 位：

| `enc_obj_r` | 含义 | 屏在不在 |
|---|---|---|
| 0 | BPM | 与现状逐位相同 |
| 1 | 变调 | 与现状逐位相同 |
| 2 | 屏选参数（由 `enc_tgt_r` 决定是 6 个里的哪一个） | 只有屏点选才会进入 |
| 3 | 预留 | 不可达 |

**推荐做法（零回归）**：EC11 按压**保持现状的 0 与 1 之间循环**，模式 2 只能由屏点选进入，屏上给一个"退出"按钮把它设回 0 或 1。这样：

- 屏不在时，EC11 的行为与今天**逐位相同**（BPM 与变调），不会因为改了对象宽度而失灵。
- 屏在时，点某个参数就进模式 2，转旋钮调它，点"退出"回到 BPM 或变调。

**可选增强**：把按压改成 0 -> 1 -> 2 -> 0 三态循环，这样脱屏也能进参数模式（进入时保持上次的 `enc_tgt_r`，复位默认 0 即失真增益）。代价是改变了现有按压行为，必须确认没有 tb 依赖它。

已核：`tb/` 下没有任何 tb 直接检查 `enc_obj_r`（只有 `tb/w3c/tb_evt_uart_rx_gate.sv:69-70` 接了 `ui_tx_start` / `ui_tx_data` 两根空线）。所以扩位的 tb 风险低，但有一个必须同步的地方：`led_indicator.enc_obj_i` 是 **1 位**（`led_indicator.v:107`）。`enc_obj_r` 扩成 2 位后如果不同步改这个端口，Verilog 会**静默截断取 LSB**，症状是"模式 2 的灯显示成 BPM 的颜色"。这正是 `led_indicator.v:108-115` 已经记录过的同一个坑（当年 `scope_mode_r` 从 1 位扩到 2 位时，FFT 被截断成波形色）。扩位时**必须同时改 `led_indicator` 的端口宽度与颜色表**。

### 4.6 EC11 按一下干什么（回答）

建议：**保持"切换对象"语义，不用它切使能开关**。

理由三条：

1. 使能开关是屏的职责。屏 2 上已经有 3 个开关控件（失真/合唱/延迟各一个），点一下比拧旋钮快，而且能一眼看到三个的当前状态。
2. 按压已经在表达"我在切换对象"（灯 5 的临时色就是这个语义，`led_indicator.v:65-68`）。让它同时兼任"切开关"会让两种语义混在一起，用户分不清"这一下是切对象还是切开关"。
3. 保持现状语义意味着零回归风险。

若将来用户觉得"屏不在时想用旋钮开效果"，再单独设计（例如长按切换使能，`debounce` 已经提供 `enc_sw_lvl` 电平，可做长按判定）。

---

## 五、推子分工与"音量颤音"档（本轮新增）

**本节定位**：档 2 需要动 rtl（`fader_gear` 加端口与三态切档、`top.v` 加 mux、`tb_fader_gear` 判据要改），所以也属"**下一轮可选增强**"（见 2.2.5），不塞进最小可用第一步。屏上"推子档"的**显示**属于第一步（`led_gear_st` 已是模块层 wire，零引线）。

### 5.1 三档分工（核代码：三组目标寄存器零交集）

| 控件 | 档位 | 调什么 | 目标寄存器 | 下游模块 | 出处 |
|---|---|---|---|---|---|
| 推子 CH2 | 档 0 | 变调，降 | `fader_gear.enc_r` -> `transpose_semi_o` | `note_manager.transpose_semi_i` | `fader_gear.v:217`、`:249`；`top.v:2909-2911`、`:5901` |
| 推子 CH3 | 档 0 | 变调，升 | 同上 | 同上 | 同上 |
| 推子 CH2 | 档 1（上电默认） | 音高颤音 深度 | `vibrato_depth_o` -> `vib_depth_sel` | `u_vibrato_lfo`（`top.v:6006`） | `fader_gear.v:259-261`；`top.v:2953` |
| 推子 CH3 | 档 1 | 音高颤音 速率 | `vibrato_rate_o` -> `vib_rate_sel` | 同上 | `fader_gear.v:259-261`；`top.v:2954` |
| 推子 CH2 | 档 2（本轮新增） | 音量颤音 深度 | 计划新增 `trem_depth_o` -> 顶层 mux -> `fx_chain.trem_depth_i` | `u_trem`（`fx_chain.v:330`） | 见 5.3 |
| 推子 CH3 | 档 2（本轮新增） | 音量颤音 速率 | 计划新增 `trem_rate_o` -> 顶层 mux -> `fx_chain.trem_rate_i` | 同上 | 见 5.3 |
| EC11 | 屏选参数 | 失真/合唱/延迟 的 6 个程度参数 | `ui_fx_gain` / `trim` / `chorlen` / `dlylen` / `fb` / `mix` | `u_fx_chain`（`top.v:6366-6372`） | `uart_ui.v:165-173` |

核验结论：推子档 0 改 `transpose_semi`（进 `note_manager`），推子档 1 改音高颤音（进 `vibrato_lfo`），推子档 2 改音量颤音（进 `fx_chain` 的 `u_trem`），EC11 改失真/合唱/延迟参数（进 `fx_chain` 的 `u_dist` / `u_chorus` / `u_delay`）。**四组目标寄存器没有交集**。用户说的"推子负责颤音和实时变调"与代码一致。

所以 2026-10-16 第一版里"A. 与 10-14 裁定冲突"那一节**作废**。2026-10-14 的裁定是"效果器参数不走 EC11、走推子参数页"；本轮把"音量颤音"划给推子档 2，EC11 只负责失真/合唱/延迟，两者不抢同一个寄存器。

**必须提醒的命名区分**（这一条容易误解）：

| 名字 | 模块 | 文件:行号 | 参数 | 谁调 |
|---|---|---|---|---|
| 音高颤音（vibrato） | `vibrato_lfo` | `top.v:6006` | `vib_depth_sel` / `vib_rate_sel` | 推子档 1 |
| 音量颤音（tremolo） | `fx_trem`（在 `fx_chain` 内） | `fx_chain.v:322-334` | `trem_depth_i` / `trem_rate_i` | 推子档 2（本轮新增），帧 `0x15`/`0x16` 也可写 |

屏上标签必须区分，建议分别写"音高颤音"与"音量颤音"，否则用户会以为调的是同一个量。

### 5.2 现状：档 2 与档 3 结构上不可达（原因）

`fader_gear.v:237-242` 原文：

```
// 'J'：档 0 与档 1 之间切
//   用 (gear_o == 0) ? 1 : 0 而不是 gear_o + 1：
//       后者一旦 gear_o 是 2/3 就会走到 3/2，预留档会被"走进去"。
//   本写法结构上保证档 2/3 不可达
if (gear_next_i)
    gear_o <= (gear_o == 2'd0) ? 2'd1 : 2'd0;
```

为什么当初要"结构上不可达"：档 2 与档 3 在 2026-10-01 的定稿档位表里是**预留**（档 2 = 摇把范围与速率，档 3 = 主音量微调），两者都**没有实现**。如果让切档走到档 2，而档 2 的语义是"预留摇把"，那么：

- 档 2 下 `vibrato_depth_o` / `vibrato_rate_o` 会被归零（`fader_gear.v:258-266` 的 `else` 分支）=> **颤音静默失效**；
- 而档 2 想驱动的"摇把"并不存在 => **两个推子什么都不做**，用户会以为推子坏了。

所以作者刻意用三元式把 2/3 排除在外，宁可"切不到"也不要"切进去没反应"。这是**有意的设计，不是遗漏**。

改法方向：把"档 2 是空档"这个前提换掉（本轮给档 2 真正的语义 = 音量颤音），然后让切档走三态循环，**并新增一条"屏直接置档 2"的入口**：

```verilog
// 入口 1：推子自己的切档循环（'J' / 矩阵 idx 5）
// 推荐写法：显式 case，档 2 可达、档 3 仍不可达
if (gear_next_i) begin
    case (gear_o)
        2'd0:    gear_o <= 2'd1;
        2'd1:    gear_o <= 2'd2;
        2'd2:    gear_o <= 2'd0;
        default: gear_o <= 2'd0;   // 2'd3 兜底回 0，保持"3 不可达"
    endcase
end

// 入口 2（本轮新增）：屏点选，直接置档 2，与当前档位无关
//   优先级：放在 gear_next_i 之后 => 同拍时"屏置档"胜（屏是明确意图）
if (gear_sel2_i) begin
    gear_o <= 2'd2;
end
```

为什么用显式 `case` 而不是 `gear_o + 2'd1`：`gear_o + 2'd1` 在 2 位下是 `3 -> 0`（回绕），行为上其实也安全，但"档 3 不可达"就变成**靠位宽回绕保证**，读代码的人看不出来；显式 `case` 把"3 兜底回 0"写成一条明线。

### 5.3 档 2 完整改动清单

#### 5.3.1 要动的文件

| # | 文件 | 改什么 | 关键约束 |
|---|---|---|---|
| 1 | `rtl/w3a/fader_gear.v` | (1) 切档改成三态循环（见 5.2）(2) **新增输入 `gear_sel2_i`**（单周期脉冲，直接置档 2）(3) 新增两个输出 `output reg [11:0] trem_depth_o, trem_rate_o` (4) 语义 mux 加档 2 分支 | **档 0 与档 1 的输出必须逐位不变**（零回归） |
| 2 | `rtl/top.v` | (1) `fader_gear` 例化加两个输出接线与 `gear_sel2_i` 接线 (2) 在 `fx_chain` 例化处加 2:1 mux（见 5.3.2） | mux 的选择信号用 `led_gear_st == 2'd2`（`led_gear_st` 是模块层 wire，`g_sound` 内可读） |
| 3 | `rtl/w3a/led_indicator.v` | **端口宽度不用改**（`gear_i` 已经是 `[1:0]`，`led_indicator.v:97`）；**颜色表也不用改**（`:224-229` 已经有 `2'd2: C_YELLOW` 这一行）；只改注释与语义标签（`:33` 表头"摇把=黄"改成"音量颤音=黄"，`:221-223` 的注释） | 若决定把档 2 的颜色从黄改成别的，则 `tb/w3a/tb_led_indicator.sv` 要同步（它逐位比对 24 位颜色） |
| 4 | `rtl/w3c/uart_ui.v` | (1) **新增输出 `gear_to_trem_o`**（单周期脉冲，由触摸控件 ID 9 触发，见 2.2.4）(2) 新增输出 `gear_next_o`（由控件 ID 13 触发，等同按一次 `'J'`）(3) 为**回读**加 2 个只读输入（`trem_depth_eff_i` / `trem_rate_eff_i`），或让回读直接读顶层算好的值 | **不需要**把推子做成写源（这是推荐路线的关键好处） |
| 5 | `tb/w3a/tb_fader_gear.sv` | **必改既有判据**（见 5.3.4），本轮不动 | 这是本条改动最大的一处连带成本 |

#### 5.3.2 档 2 的接线（推荐路线：在 `fx_chain` 例化处做 mux）

关键结构约束：`ui_fx_depth` / `ui_fx_rate` 是 `uart_ui` 内部的 `output reg`（`uart_ui.v:171-172`），顶层只能读、不能写。所以**不能**让推子直接驱动这两个寄存器。

推荐做法：**不去动 `uart_ui` 的写入口**，而是在 `fx_chain` 的例化处把"生效值"选出来：

```verilog
// 档 2 时音量颤音由推子控制；其余档由 uart_ui 的寄存器控制
wire        trem_from_fader = (led_gear_st == 2'd2);
wire [11:0] trem_depth_f;    // <- fader_gear.trem_depth_o
wire [11:0] trem_rate_f;     // <- fader_gear.trem_rate_o
wire [7:0]  trem_depth_eff  = trem_from_fader ? trem_depth_f[11:4] : ui_fx_depth;
wire [7:0]  trem_rate_eff   = trem_from_fader ? trem_rate_f[11:7]  : ui_fx_rate;

// fx_chain 例化处（top.v:6372）
.trem_depth_i(trem_depth_eff), .trem_rate_i(trem_rate_eff),
```

位宽换算（12 位推子 -> 8 位寄存器，`fx_chain.DEPTH_W = RATE_W = 8`，`fx_chain.v:110-111`）：

| 参数 | 推子源 | 映射 | 得到的范围 | 说明 |
|---|---|---|---|---|
| 深度 `depth` | `ch2_i`（12 位，0..4095） | `[11:4]` | 0..255 | 全行程都有意义（0 = 数值恒等，255 = 最深）。**注意**：帧路径受 `0xFF` 帧尾限制只能到 254（`uart_ui.v:159-161`），推子能到 255，是帧路径的**超集**，无害 |
| 速率 `rate` | `ch3_i`（12 位，0..4095） | 建议 `[11:7]` | 0..31 | **必须缩放**：默认速率是 7（`fx_trem.v:86` 的 `RATE_DEFAULT = 8'd7`），而 `RATE_W = 8` 允许 0..255。若直接取 `[11:4]`，推子前 3% 的行程就覆盖了整个常用区间，后面 97% 全是"过快"=> 手感极差。取 `[11:7]` 给 0..31 更合理，但**具体系数待上板听感确定** |

推荐路线与备选路线的取舍：

| 路线 | 做法 | 评价 |
|---|---|---|
| A（推荐） | 在 `fx_chain` 例化处 mux 生效值 | 对 `uart_ui` 的写入口零改动；不引入"推子 vs 帧 vs EC11"三方仲裁；代价是 `ui_fx_depth`/`ui_fx_rate` 在档 2 下"写了不生效" |
| B | 把推子做成 `uart_ui` 里深度/速率影子寄存器的第三个写源 | 语义统一（所有写源都进同一个影子），但要加优先级仲裁，而且 `fader_gear` 已有的"推子动过才接管"边沿检测（`fader_gear.v:199-211` 的 P3.1/P3.2）要为档 2 再做一套 => 复杂度明显更高 |

**路线 A 必须写清的语义（属于"静默无效"，与 `K-106` 纪律有张力，必须处置）**：

档 2 下，帧 `0x15` / `0x16` 对 `ui_fx_depth` / `ui_fx_rate` 的写入**仍然会写进寄存器，但不影响出声**（被 mux 挡住）。处置三条：

1. 屏上 `depth` / `rate` 显示**生效值**（即 mux 之后的值），并在旁边标注"推子控制"，不要显示 `ui_fx_depth` 的原值。
2. 退出档 2 后，`ui_fx_depth` / `ui_fx_rate` 回到帧设的值 => 行为可预期（"推子只管档 2 期间"）。
3. 回读通路要把"当前档位"和"depth/rate 是否由推子控制"一起报给屏，否则用户看到数值在动却不知道是谁在动。

#### 5.3.3 判据（必须能红）

新增或扩 `tb/w3a/tb_fader_gear.sv`：

```
a. 复位后 gear == 1（不变）
b. 按一次 'J' -> gear == 2
c. 再按一次   -> gear == 0
d. 再按一次   -> gear == 1（三态循环闭合）
e. 档 2 时：trem_depth_o 跟随 ch2_i、trem_rate_o 跟随 ch3_i；
   🔴 而 vibrato_depth_o/vibrato_rate_o **保持**（= 离开档 1 时的最后值，⛔ 不清零）
f. 档 1 时：vibrato_depth_o 跟随 ch2_i、vibrato_rate_o 跟随 ch3_i；
   🔴 而 trem_depth_o/trem_rate_o **保持**（= 离开档 2 时的最后值，⛔ 不清零）
g. 档 0 时：四个输出**全部保持**（⛔ 不再是"全 0"）；
   ⚠️ 复位后它们本来就是 0，所以"上电不动推子 => 两个颤音都是关的"仍然成立
h. 档 2 时发 'H' 24 -> transpose_semi_o == +12
   （依据 fader_gear.v:214-218：trans_down/up/abs_i 优先级最高、与档位无关
     => 档 2 下串口仍能改变调，这是"保持"语义而不是"锁死"）
i. 切回档 1 -> vibrato 重新跟随 ch2_i/ch3_i；trem 保持离开档 2 时的值
j. 切回档 0 -> 推子接管变调（沿用现有 G 组的接管判据）

⭐ 判据 k（新增，专验"共存"）：档 1 把 ch2 推到 0x800 -> 切档 2 把 ch3 推到 0x400
   -> 切回档 1：vibrato_depth_o 仍是 0x800（保持）且 trem_rate_o 仍是 0x400（保持）
   => 两个颤音同时有效
```

入口 2（屏直接置档 2，本轮新增）：
k. 档 0 时给一个 gear_sel2_i 脉冲 -> gear == 2（一条命令一定落到档 2）
l. 档 1 时给一个 gear_sel2_i 脉冲 -> gear == 2
m. 档 2 时再给一个 gear_sel2_i 脉冲 -> 仍是 gear == 2（幂等，不会绕走）
n. gear_sel2_i 与 gear_next_i 同拍 -> 以 gear_sel2_i 为准（gear == 2）
o. gear_sel2_i 只高 1 拍 -> 下一拍起 gear 保持 2（不是脉冲式回弹）

变红方式：
  - 把 case 写成 gear_o + 2'd1 且不写 default 兜底 -> 可能进档 3 -> 红
  - 把 trem_depth_o 与 vibrato_depth_o 接成同一个信号 -> e / f 必红（档 2 与档 1 输出相同）
  - 档 2 分支忘了给 vibrato_* 归零 -> f 必红
  - 把 gear_sel2_i 写成"再发一次 gear_next_i"（循环而非直置）-> k / l / m 里至少两条红
  - 把 gear_sel2_i 放在 gear_next_i 之前 -> n 红
```

`rtl/top.v` 侧（顶层判据，可加在 `tb/top/tb_top_fx_audio.sv` 或新增）：

```
k. 档 1（默认）：改 ui_fx_depth 后出声的颤音深度跟着变（走寄存器）
l. 档 2：改 ui_fx_depth 后出声的颤音深度【不】跟着变，而是跟着推子走
   （判据：分别拨动 ch2 与发帧 0x15，看哪一个影响 trem 深度）
m. 退出档 2 回到档 1：ui_fx_depth 的值重新生效（回到帧设的值）
变红方式：把 mux 的选择信号写成常量 0（永远用寄存器）-> l 红
```

#### 5.3.4 影响面（必须知道的连带成本）

**必改的既有判据（这是本条改动最要紧的影响面）**：

`tb/w3a/tb_fader_gear.sv` 里有两处**依赖"档 2/3 不可达"和"按一次从档 1 落到档 0"**的判据，档 2 可达后**必红**：

| 位置 | 原文 | 为什么红 |
|---|---|---|
| `:76-78` | `always @(posedge clk) if (rst_n && (gear == 2'd2 \|\| gear == 2'd3)) bad_gear = bad_gear + 1;` | D 组的连续监视把**档 2 也算违规**。档 2 可达后 `bad_gear > 0` => 必红。必须改成只监视 `2'd3` |
| `:302` | `pulse_gear(); chk("G9 -> gear0", gear == 2'd0);` | 从档 1 按一次，新循环落到**档 2**，不是档 0 => G9 必红 |
| `:330` | `pulse_gear(); // -> gear0` 然后 `:332` `chk_semi("G12 ...", 0)` | 复位后从档 1 按一次落到**档 2** => G12 必红（它断言"档 0 下推子未动 => 0"） |
| `:333-334` | `chk_semi("G13 ...", 0)` | 同上 => G13 必红 |
| `:341` | `pulse_gear(); // -> gear0` 然后 `:343` `chk_semi("G14 ...", -12)` | 同上 => G14 必红 |
| `:345` | `chk_semi("G15 ...", -12)` | 同上 => G15 必红 |

修法：加一个 `pulse_gear_to(target)` 辅助任务（连续按 `'J'` 直到 `gear == target`，带次数上限），把需要落到档 0 的地方改成按两次。注意 G12-G15 在 tb 里被标注为 `[smoke]`（冒烟检查），但它们的 `chk` / `chk_semi` **仍然会累加 `errors`** => 回归会红，不能因为标了 smoke 就忽略。

**要重跑的验证**：

| 项 | 要不要重跑 | 理由 |
|---|---|---|
| `tb/w3a/tb_fader_gear.sv` | 要，且**判据要先改** | 切档逻辑改了 |
| `tb/w3a/tb_led_indicator.sv` | 只在改档 2 颜色时才要 | 颜色表已有档 2 行，保留黄色则不用改 |
| `tb/w3c/tb_fx_chain.sv` / `tb_fx_trem.sv` | 不用 | mux 在 `top.v` 的例化处，模块级行为不变（`en_i` 仍是 `1'b1`，端口语义不变） |
| 凡在顶层按过 `'J'` 或矩阵 idx 5 的 tb | **要核对** | 一次按键的落点从"档 0"变成"档 2"=> 那些 tb 的期望值可能变 |
| 全量回归 | 要 | 改了两个 RTL 模块 |
| **PnR** | **要** | 新增 2 个 12 位输出 + 一个 8 位 2:1 mux + 档位 case 改动 => 必须重新综合与布局布线（按项目纪律：先 PnR 再回归） |

另一条要提醒的：档 2 时 `led_gear_st == 2'd2` => 灯 3 变黄（"推子功能"灯）。而**效果器使能灯 8**（`top.v:7075`，`ui_fx_en = |ui_fx_mask[2:0]`）反映的是"效果器开没开"。两者语义不同（一个说"推子现在管什么"，一个说"效果器开没开"），不要混。

### 5.4 音量颤音的归属：已定归推子档 2

用户第三轮拍板："效果器链里面也保留音量颤音这个大块吧，点到这个的时候推子自动切换到音量颤音档位"。

所以：

| 项 | 结论 |
|---|---|
| 链式图上 | **保留音量颤音节点**（第 5 个节点），并自带 depth / rate 两个控件 |
| 谁调 depth / rate | **推子档 2**（CH2 = 深度，CH3 = 速率），连续扫 |
| EC11 目标清单 | **定为 6 个**：gain / trim / chorlen / dlylen / fb / mix。**不含 depth / rate** |
| 进入方式 | 点音量颤音节点（或它的 depth / rate 控件）=> 屏发 `65 09` => 推子切到档 2 |
| 屏上表现 | 该节点与两个控件转"推子接管高亮"（橙），数值随推子实时变（靠回读） |

这样定的理由四条：

1. 用户明确"音量颤音也由推子调"，且明确要在链上保留这一块。
2. 推子是**连续行程**（可以一扫而过），适合"深度从 0 扫到满"这种大范围量；EC11 是加减 1 的微调，6 个参数已经要拧很多圈。
3. 若 EC11 也写 depth / rate，就会变成三方仲裁（帧 `0x15`/`0x16` / EC11 / 推子）。`fader_gear` 已有"推子动过才接管、串口设的值保持到推子动"那套边沿检测（`fader_gear.v:199-211` 的 P3.1/P3.2，用**量化档位**做迟滞）。5.3.2 的路线 A 正是为了避开这个复杂度。
4. EC11 目标数保持 6，屏 2 的分工更清楚：音量颤音节点一看就是"推子控制"，失真/合唱/延迟一看就是"EC11 步进"。

将来若用户想让 EC11 也能微调 depth / rate（例如脱开推子时精调），再单独加：那时 EC11 目标回到 8 个，并且要补一条"档 2 下 EC11 与推子谁优先"的规则。**本轮不做。**

### 5.5 档 2 的两条进入方式（写同一个寄存器）

档 2 有两条入口，都落到同一个寄存器 `fader_gear.gear_o`：

| 入口 | 操作 | 路径 | 落点 |
|---|---|---|---|
| 1 推子自己的切档循环 | 串口 `'J'`（`calib_cmd.CMD_GEAR_NEXT`）或控制板矩阵 idx 5 | `cmd_gear_next_req` => `fader_gear.gear_next_i` | `case` 三态循环：档 0 -> 1 -> 2 -> 0 |
| 2 屏点选 | 点音量颤音节点或其 depth / rate 控件 | 屏发 `65 09` => `uart_ui` 出 `gear_to_trem_o` 脉冲 => 顶层 OR 进 `fader_gear.gear_sel2_i` | **直接写 `2'd2`**（与当前档位无关） |

两条写同一个寄存器，所以：

- 后写者胜（与 `play_seq` 的 `bpm_load` / `bpm_up` 同一手法，`play_seq.v:339-344`）。不需要仲裁器。
- 屏上的"推子档"显示（状态条第 5 项）永远反映 `led_gear_st`，所以无论从哪条入口进档 2，屏都会跟着变。
- 档 2 与 `enc_obj_r` **互不影响**：前者是"推子管什么"，后者是"EC11 管什么"。两者可以同时是"音量颤音"与"某个失真参数"。

---

## 六、协议建议

### 6.1 现有协议（已核）

方向 1：屏到 FPGA（唯一活着的方向）

```
TJC 返回帧：  <返回码> <帧体...> 0xFF 0xFF 0xFF
返回码（uart_ui.v:204-207）：
  0x65  控件点击事件     -> body_q = 控件 ID
  0x70  字符串变量返回   -> 不落地（uart_ui.v:485）
  0x71  数值变量返回     -> body_q = 变量序号，val_q = 值
  0x88  系统启动成功     -> 握手（置 hb_ready_o，无帧体）
```

已实现的写入点：

| 功能 | 帧 | 落地 |
|---|---|---|
| 模式翻转 | `65 00 FF FF FF` | `mode_o <= ~mode_o`（`uart_ui.v:373-375`） |
| Test Mode 切档 | `65 02 FF FF FF` | 关 -> 4 -> 8 -> 16 -> 32 -> 关（`:376-388`） |
| 起始音 | `71 01 <v> FF FF FF` | `base_semi_o <= v>>1`（`:414-419`），屏发 `0/24/48` |
| 效果器 9 项 | `71 10..18 <v> FF FF FF` | `fx_*_o`（`:428-483`） |
| 开关翻转（点节点标题） | `71 10 <新掩码> FF FF FF` | `fx_mask_o <= val_q`（**已实现**，`uart_ui.v:428-430`）。屏本地翻位后整帧写出，见 6.5 |

方向 2：FPGA 到屏（现状不通，见 3.2）。

现有"回读"能力盘点：

| 形式 | 命令 | 回包 | 含值 |
|---|---|---|---|
| 命令受理回执 | `'A'` / `'W'` / `'B'` / `'K'` / `'O'` / `'U'` / `'I'` / `'D'` / `'Q'` / `'J'` / `'R'` / `'L'` / `'C'` | 单字节（`'a'` / `'w'` / `'b'` / `'k'` / `'o'` / `'u'` / `'x'` 等） | 不含 |
| Test Mode 回执 | `'M'` | 单字节 `'4'` / `'8'` / `'A'` / `'B'` / `'0'` | 含档位（唯一含值的单字节回执） |
| 标定进度 | `'S'` | 单字节轴号加拒绝原因码 | 部分 |
| pos 探针 | `'P'` | 8 字节 `P<ch><4 位十进制>` 加 CRLF | 有 |
| 逐轴探针 | `'N'` | 8 字节（逐轴自动切） | 有 |
| span 状态 | `'V'` | 7 字节 `V<state><axis><rej_hi><rej_lo>` 加 CRLF | 有 |
| 事件上行 | `'O'` 开 | 14 字节 `0xA5` 加 type 加 seq 加 tick(4) 加 axis 加 inc(4) 加 vel 加 xor | 有，但只是音符事件 |

结论：现有协议几乎没有值回读。30 条状态里只有 4 条能读回来（`'P'` / `'N'` / `'V'` / `'M'`），其余 26 条屏上全是本地缓存。这正是本次要做的事。

### 6.2 回读帧格式建议

设计原则（全部对齐本项目既有约定）：

| 原则 | 理由与先例 |
|---|---|
| FPGA 到屏不新造帧头，直接发 TJC 指令文本 | 屏认的是 `t0.txt="..."` / `n0.val=45` / `j0.val=100` 这类文本，帧尾 `FF FF FF`。`esp32/串口屏控件清单.md:240-258` 已有一整套实测通过的写法，照抄 |
| FPGA 直接发完整 TJC 指令，不是"发值、屏自己拼" | 屏自己不会拼。这与 ESP32 侧 `hmi.c` 的做法一致 |
| 屏到 FPGA 的"读请求"复用 `0x71` 帧 | `body_q` 已能区分变量号，新增变量号即可，不动帧格式 |
| `0xFF` 是帧尾，所以值域上限 254 | `uart_ui.v:159-161` 已论证，这是 TJC 协议的固有约束 |
| 回读帧不用 `0xA5` 帧头 | `0xA5` 是曲谱帧头（`evt_upstream.v:10`）。虽然曲谱已改走 `G22`，但板载口的 `'P'` / `'V'` 诊断包仍在，不要混 |

建议格式（推荐方案 A）：

```
触发时机三类：
  1. 屏发读请求帧：71 <状态 ID> <任意值> FF FF FF
  2. 状态变化时主动推（事件驱动）
  3. 收到 0x88 握手后推一遍全量快照（初始化）

FPGA 到屏的字节流（ASCII，每条以 FF FF FF 结尾）：
  n0.val=120<FF FF FF>              BPM
  t1.txt="指板"<FF FF FF>           模式
  n1.val=3<FF FF FF>                变调（+3）
  t2.txt="BASS"<FF FF FF>           音色
  n2.val=2<FF FF FF>                EC11 当前目标（0..5）
  n3.val=2<FF FF FF>                推子档位（0/1/2）
  t3.txt="DIST+DLY"<FF FF FF>       效果链
  ...

优点：屏侧零代码（只要拖控件），与 ESP32 侧同一套做法（已被验收）
长度：一条状态约 15..25 字节，30 条约 600 字节
耗时：500 kbaud 下约 10 ms，115200 下约 52 ms，对参数面板都够
```

备选方案 B（紧凑二进制，只在要高频刷时用）：

```
  0xA5 | 0x03(类型=状态回读) | seq(1) | 状态 ID(1) | 值(4, 大端) | XOR(1)   共 9 字节
  与 rec_dump / evt_uart_rx 的 9 字节帧同构
  缺点：屏侧要写解析代码（TJC 的 printh / prints 能做，但麻烦）
```

推荐方案 A。本次目标是"能显示"，不是"最高带宽"。屏自带字库、数值控件、进度条，让屏做显示、让 FPGA 只发文本，这是 `产品形态决议清单.md:597-607` 已经论证过的分工。将来若要画实时波形（100 点乘 4 字节等于 400 字节每帧，约 28 fps），那时再上方案 B。

### 6.3 状态 ID 与控件 ID 分配建议

| 段 | 用途 | 现状 |
|---|---|---|
| 控件 ID 0..2 | 模式 / 起始音 / Test Mode | 已占（`uart_ui.v:373-388`） |
| 控件 ID 3..8 | EC11 目标 0..5（**下一轮可选增强**，见 2.2.5） | 建议新增 |
| 控件 ID 9 | 推子切到档 2（**下一轮可选增强**） | 建议新增 |
| 控件 ID 10..12 | 预留（本轮不用：开关翻转走现有 `71 10` 帧，不占控件 ID） | 空闲 |
| 控件 ID 13 | 推子档循环（等同按一次 `'J'`，**下一轮可选增强**） | 建议新增 |
| 控件 ID 14 | 退出选中（**下一轮可选增强**） | 建议新增 |
| 控件 ID 15..31 | 屏上其余按钮（tare / span / 刷新 / 16 轴子页） | 建议新增 |
| 变量号 `0x10`..`0x18` | 效果器 9 参数 | 已实现（`uart_ui.v:150-158`） |
| 变量号 `0x20`..`0x2F` | 读请求（状态 ID） | 建议新增 |
| 变量号 `0x30`..`0x3F` | 标定页 | 建议新增 |
| 变量号 `0x40`..`0x4F` | 调试页 | 建议新增 |
| 变量号 `0x7F` | 未知变量号，静默丢弃 | 已实现 |
| 变量号 `0x80`..`0xFF` | 曾因 `body_q` 只有 7 位而发生别名（`0x90` 被当成 `0x10`），已于 `uart_ui.v:220-243` 修好（扩到 8 位），现在这些值落进"未知变量号"被丢弃 | 已修 |

### 6.4 BPM 前置（必须先做，否则屏上显示不了 BPM）

BPM 在 FPGA 里**没有数字寄存器**。tempo 状态只有 `play_seq.tick_inc_o`，它是一个 32 位相位增量，语义是：

```
tick_inc = BPM 乘 1374 加 47        （play_seq.v:176-181）
验算：120 乘 1374 加 47 = 164927，与 TICK_INC_DEFAULT 逐位相同
40 BPM -> 55007，240 BPM -> 329807
```

要从 `tick_inc` 反推 BPM 需要一个除法器，不值得。正确做法是**在 `play_seq` 里加一个 8 位的当前 BPM 寄存器**：

```verilog
output reg [7:0] bpm_cur_o    // 当前 BPM（40..240）
```

三条写路径都要更新它：

```
bpm_load_i  分支：bpm_cur_o <= bpm_clamped        （限幅后的目标值，play_seq.v:196-197）
bpm_up_i    分支：bpm_cur_o <= (bpm_cur_o >= 240) ? 240 : bpm_cur_o + 1
bpm_dn_i    分支：bpm_cur_o <= (bpm_cur_o <=  40) ?  40 : bpm_cur_o - 1
复位：bpm_cur_o <= 120（与 TICK_INC_DEFAULT 对应）
曲谱 kind=2 事件：tick_inc 被换速事件直接写（play_seq.v:322-324），此时 bpm_cur_o 无法从 inc 反推
```

最后一条是**必须如实标注的局限**：曲谱 `kind=2` 事件直接写 `tick_inc_o`，不经过 BPM 语义，所以 `bpm_cur_o` 在"曲谱换速"之后会与真实 tempo 不一致。两种处理：

1. 屏上把 BPM 显示成"约"或加一个"由曲谱控制"标记。
2. 或者用 `bg_beat` 实测：数 1 秒内的拍点数得到实际 BPM（分辨率为 1，1 秒窗口下误差约 1 BPM），显示成"实测 BPM"。这是地面真相，但需要 1 秒窗口。

建议：`bpm_cur_o` 用于手动设定值显示，另可选加一个"实测 BPM"用于校验。先做前者。

这个改动很小（约 8..16 个 FF），但**必须重跑 `tb/w3c/tb_play_seq.sv`**，因为三条写路径的限幅语义不能变。

### 6.5 "点一下翻转开关"怎么落地（本轮简化：不新增协议）

用户第四轮要求"点失真/合唱/延迟，点一下就翻转状态"，随后澄清"不一定要实现翻转，我的意思是状态翻转。反正能实现功能就行了"。

所以本节的结论是**一句话**：

```
沿用现有协议：屏点一下 -> 屏自己算出新的掩码值 -> 发 71 10 <新掩码> FF FF FF
屏本地维护掩码缓存，点击时翻转对应位再整帧写出
```

| 项 | 内容 |
|---|---|
| 帧 | **`71 10 <新掩码> FF FF FF`**，即现有的"写整个掩码"帧（`uart_ui.v:428-430`，`fx_mask_o <= val_q` 直传）。**不新增帧、不新增寄存器、不改 FPGA** |
| 屏侧做什么 | 维护一个本地掩码缓存；收到触摸回调时 `mask_local <= mask_local ^ 对应位`，然后发上面那一帧，并按新值重绘该节点 |
| 掩码位序 | bit0 = 失真，bit1 = 合唱，bit2 = 延迟（`fx_chain.v:180-182`）。bit3 是混响留位、bit4 空闲，**不要动** |

**风险一行**：掩码目前**没有回读通路**（`top.v:1217` 的 `tx_busy_i = 1'b1`，见 3.2），而串口助手与屏**共用同一条 UART**（`top.v:1109`）。所以若别人改了掩码，屏的本地缓存会**过期**，屏下一次整帧写出会**静默覆盖**对方的改动。**正常单人使用时不会发生**（只有屏在写）；回读通路做完之后（第八节的 S0），屏的缓存可以由回读自动对齐，这条风险自然消失。

本轮**不做**"FPGA 侧原子异或"那种方案（它要新增 3 个 `RET_TOUCH` 分支）。留作下一轮可选增强，见 2.2.5。

## 七、缺口清单（没有回读通路的状态，屏上不可信）

这一节是本文最要紧的结论。

判据：只要"FPGA 到屏"没有携带该值的字节，屏上那个数字就只是它自己发出去的缓存。一旦别的来源改了同一个量（矩阵键、EC11、推子、串口助手、曲谱事件、上电默认），屏上就会撒谎。

### 7.1 完全无回读（屏上不可信），26 条

| 危险度 | 状态 | 会被谁偷偷改掉，屏立刻撒谎 |
|---|---|---|
| 最高 | BPM | 曲谱 `kind=2` 事件会改 BPM（屏上还显示旧值）、EC11、串口 `'Q'` |
| 高 | 变调 `transpose_semi` | 4 个来源：推子（档 0）、串口 `'F'`/`'G'`/`'H'`、EC11、矩阵键14 |
| 高 | 模式（指板 / 钢琴） | 3 个来源：串口 `'A'`、矩阵模式键、屏触摸控件 0 |
| 高 | EC11 当前目标 | EC11 自己（若按压也能换对象）与屏点选 |
| 高 | 效果器 `mask` 加 6 个参数 | 串口助手（与屏共用同一条 UART）、EC11、屏自己点节点标题翻开关。**这一条是本轮最需要回读的**：屏上"开/关"文字与底色若来自本地缓存，串口助手一改掩码屏就撒谎（见 6.5） |
| 高 | 推子档位 | 串口 `'J'`、矩阵 idx 5（本轮新增档 2 后更重要：档位决定推子管什么） |
| 高 | 音量颤音深度与速率（生效值） | 推子档 2（连续变）、帧 `0x15`/`0x16`（档 2 下不生效但值会变） |
| 高 | 各轴 `tare` / `span` | `'T'` / `'S'`。标定页要显示的零点与满程现在完全读不到 |
| 中 | 滑音、音色、节拍器、鼓机节奏型、键盘打鼓、looper 已录事件数、Test Mode 权威状态 | 各有 1..2 个非屏来源（串口字母或矩阵键） |
| 低 | 起始音（唯一只屏能改的）、引导模式、显示模式、复音占用 | 无 |

### 7.2 只有间接通路（有回包但不含值），6 条

| 状态 | 现有回包 | 缺什么 |
|---|---|---|
| 模式 / 滑音 / 节拍器 / 键盘打鼓 / 引导 / 音色 / 节奏型 / 推子档 | 单字节受理回执（`top.v:3704-3726`） | 回包里没有新值，只能确认"命令被受理"，不能确认"现在是几档" |
| `at_done` / `at_skip` / `at_fail` | `'T'` 完成回包（`:3709`）加 `fault_sticky` 快闪 | 分不出"哪一轴被跳过" |
| `af_fault` / `mx_fault` / `ovf_any` 的分源 | 全部取或成 `fault_any_w`（`:2845`），一个心跳灯快闪 | 8 个溢出源加 3 个故障源合成 1 个 bit，"哪一路溢出了"完全看不到 |
| `ui_frame_cnt` / `ui_resync_cnt` / `ui_err_cnt` | 已接出到 `top.v` wire | 无消费者，被综合剪掉（与 `P0-29` 同一类问题） |
| `ui_hb_ready` | 已接出 | 无消费者，被剪 |
| `ps_underrun` / `ps_tempo_applied` / `bpm_pending_obs` / `bg_bar_cnt` / `mx_n_active` / `ps_cur_tick` | 都在 `g_sound` 里 | 全部只有 2 处出现（声明加端口映射），无消费者，被剪 |

### 7.3 一个必须警惕的机制（会让屏看起来对、其实错）

`uart_ui` 有两处**静默丢弃**：

1. 帧体不足：`uart_ui.v:410-413`，`RET_NUM` 帧若 `body_len < 2`，什么都不做（不落地、不发脉冲）。
2. 未知变量号：`:486` 的 `default` 分支，什么都不做。

也就是说，屏发了帧但没生效时，FPGA **不回任何错误**。结合"屏上显示的是本地缓存"，症状就是"屏上数字变了，实际没变"，这比"不显示"危险得多。

本轮又多了一处**语义上的静默无效**：档 2 下帧 `0x15`/`0x16` 写了 depth/rate 但被 mux 挡住（见 5.3.2）。处置办法已写在 5.3.2 第 3 条（回读要同时报档位与"谁在控制"）。

建议：回读通路上线后，屏每次写完必须回读确认。或者在回读协议里给"写失败"加一个错误码（当前是静默的，属于可选增强，见第九节）。

---

## 八、最小可用第一步（具体到文件与判据）

按"先打通一条窄通路、再扩宽"的做法，第一步只做三件事：把发送通路建起来、把 BPM 寄存器加上、把 6 个字段回读出去。

**屏 2 需要的 FPGA 侧改动，只有这三样**（用户第四轮明确"不要扩大范围"）：

| # | 改动 | 为什么需要 |
|---|---|---|
| 1 | **回读通路**（`uart_ui` 加发送器 + `top.v` 接 `u_tx_fifo`） | 屏 2 上的开关状态、参数值、链节点高亮**全靠它**刷新（否则屏只能显示本地缓存） |
| 2 | **6 个零引线字段**进回读表 | 其中"效果链 `ui_fx_mask`"就是屏 2 三个开关的显示源 |
| 3 | **`play_seq` 加 `bpm_cur_o`** | 状态条要显示 BPM |

**屏 2 的参数写入与开关翻转，不需要任何 FPGA 改动**：

| 屏 2 要做的 | 用什么 | 状态 |
|---|---|---|
| 改参数值（滑条 / 数字 / 加减） | 现有 `71 11..18 <值> FF FF FF` | **早已实现**（`uart_ui.v:431-483`） |
| 开关开/关（点节点标题翻转） | 屏本地翻位 + 现有 `71 10 <新掩码> FF FF FF` | **早已实现**（`uart_ui.v:428-430`） |

=> 也就是说：**回读通路一做完，屏 2 就是一个能看、能点、能改的完整页面**（只是"用 EC11 手拧"这一条要等下一轮，见 2.2.5）。

### 8.1 回读哪 6 个字段（全部在模块层，零引线）

| 字段 | 顶层线 | 行号 | 屏上控件 |
|---|---|---|---|
| 模式 | `play_fretboard_mode` | `top.v:1255` | `t` 文本 |
| 滑音 | `slide_on_r` | `top.v:599` | `t` 文本或色块 |
| 变调 | `transpose_semi` | `top.v:969` | `n` 数字（带正负号） |
| 音色 | `timbre_sel_r` | `top.v:657` | `t` 文本 |
| 效果链 | `ui_fx_mask` | `top.v:1166` | `t` 文本（如 `DIST+DLY`）**与屏 2 三个节点的开/关显示** |
| 故障 | `fault_sticky` | `top.v:6716` | 色块 |

加第 7 条 BPM（需先做 6.4 的 `bpm_cur_o`）。

选这 6 条的理由：它们全部在 `generate` 之外，**不需要往模块层引任何线**，所以第一步的风险面只有"发送器"和"BPM 寄存器"两块。

### 8.2 要动的文件

| 文件 | 改什么 | 说明 |
|---|---|---|
| `rtl/w3c/uart_ui.v` | **只加回读发送器**（文本拼装 FSM，照 `pos_probe.v` 的结构：文本加 ready 握手） | 不加 `enc_tgt_r`、不加影子寄存器、不加 `enc_up_i` / `enc_dn_i`（那些是 2.2.5 的下一轮增强） |
| `rtl/top.v` | `uart_ui` 例化处接 `tx_busy_i` / `tx_done_i`（现在是 `1'b1` / `1'b0`）；把 `ui_tx_start` / `ui_tx_data` 接进 `u_tx_fifo` 的 `push_i` / `data_i` | 第一步只接发送通路；6 条状态已在模块层，零引线 |
| `rtl/w3c/play_seq.v` | 新增 `bpm_cur_o`（8 位），三条写路径都更新它 | 见 6.4 |
| `constr/top.cst` | 不改 | 复用现有 `D14` / `D15` |

21 条 `g_sound` 内状态的引线**留到第二步**（它们手法与 `led_gear_st` / `led_looper_st` / `led_beat` 完全相同，`top.v:1719-1734`：在 `generate` 之外声明模块级 wire，由 `g_sound` 与 `g_silent` 两个互斥分支各自驱动，不能留悬空否则 `g_silent` 档会成 `x`）。

### 8.3 判据（必须能红）

四条判据，每条都给出"怎么让它变红"。（判据 5 见 6.5 已删，本轮不新增协议所以不需要翻转判据。）

判据 1（`bpm_cur_o`，改 `tb/w3c/tb_play_seq.sv`）：

```
a. 复位后 bpm_cur_o == 120
b. bpm_load_i 送 200 -> bpm_cur_o == 200
c. 连发 bpm_up_i 到 240 后再发一次 -> 保持 240（限幅）
d. 连发 bpm_dn_i 到 40 后再发一次 -> 保持 40（限幅）
e. 送 0 -> bpm_cur_o == 40（限幅下界）
f. 送 255 -> bpm_cur_o == 240（限幅上界）
变红方式：把任一条限幅去掉，c / d / e / f 立刻红
```

判据 2（回读发送器，新增 「tb/w3c/tb_hmi_status.sv」（历史引用，当前未收录） 或扩 `tb_uart_ui.sv`）：

```
a. 给定固定状态（BPM=120，模式=指板，变调=+3，音色=BASS，mask=0x05，fault=0），
   发一次"全量快照"请求
b. 断言串口输出字节序列逐字节等于
   'n0.val=120' + FF FF FF + 't1.txt="指板"' + FF FF FF + ...
c. 断言两条命令之间没有交错（前一条的 FF FF FF 之后才是下一条的第一个字节）
变红方式：把文本表里任一个字符改错，a / b 立刻红；
          把"等空闲再发"改成"看 ready 就发"，c 红（这是 uart_tx_fifo.v:116-129 记录的错位坑）
```

判据 3（屏点选加 EC11 步进，扩 `tb/w3c/tb_uart_ui.sv`）：

```
a. 发 65 03 FF FF FF -> enc_tgt_o == 3'd0
b. 发 65 08 FF FF FF -> enc_tgt_o == 3'd5
c. 发 71 10 01 FF FF FF -> fx_mask_o == 8'h01（**现有帧**，不是新增协议；见 6.1）
d. enc_tgt_o == 0 时给一个 enc_up_i 脉冲 -> fx_gain_o 由 16384 变 17408（加 16'h0100）
e. 连发 enc_up_i 到上限后再发 -> 保持 16'hFE00（饱和，对应字节 254）
f. 连发 enc_dn_i 到下限后再发 -> 保持 16'h0000
g. enc_tgt_o == 2 时给一个 enc_up_i 脉冲 -> fx_chorlen_o 由 736 变 768（加 11'd32），
   且 fx_gain_o 不变
h. 发 71 11 64 FF FF FF（帧路径设 gain=64）-> fx_gain_o == 16384；
   再发 71 11 65 FF FF FF -> 17408。
   即"屏发 65"与"EC11 从 64 拧一格"必须得到同一个值
i. 发 65 09 FF FF FF -> gear_to_trem_o 出一个单周期脉冲（且只出一拍）
j. 发 65 13 FF FF FF -> gear_next_o 出一个单周期脉冲
k. 发 65 14 FF FF FF -> enc_obj_r 回 0
l. 发 65 09 FF FF FF -> enc_tgt_o **不变**（点音量颤音节点只切推子档，不动 EC11 目标，
   这是 2.2.3 第 4 条约定：两条通路独立）
变红方式：去掉饱和，e / f 红；
          把 EC11 那一路另写一套换算（不复用），h 红（这正是 4.4 说的最容易埋的坑）；
          不按 enc_tgt_o 选参数（6 个一起动），g 红；
          把 65 09 与某个 enc_tgt_r 分支写在一起（顺手也设目标），l 红
```

判据 3 的 h 组是**最重要的一条**，它守的是"帧路径与 EC11 路径逐位一致"这个契约。

判据 4（推子档 2，改 `tb/w3a/tb_fader_gear.sv`）：见 5.3.3 的 a..o，加 `tb/top/tb_top_fx_audio.sv` 的 k..m。

（判据 3 与判据 4 都属于**下一轮可选增强**，见 2.2.5；最小可用第一步只需判据 1 与判据 2。开关翻转走现有 `71 10`，不新增协议，所以不需要新判据。）

### 8.4 第一步之后的扩宽路径

```
第一步（最小可用）：回读通路 + 6 个零引线字段 + bpm_cur_o
                  => 屏 1 / 屏 2 / 屏 3 的"显示"全通，屏 2 的参数改值与开关翻转也已可用
第二步：把 21 条 g_sound 内状态引到模块层，屏 1 与屏 3 的其余字段接上
第三步：屏 2 的链式图细化（5 个节点，其中 3 个节点标题可点翻转开关，8 个参数控件），
        两类高亮与回读联动（开关状态靠 ui_fx_mask 回读，选中靠本地状态）
第四步（下一轮可选增强，见 2.2.5）：EC11 选中参数 + 推子档 2 + 推子档循环
第五步：把 mx_n_active（复音占用）、ui_frame_cnt 等"被剪的观测线"接上消费者
第六步：溢出分源（8 个 bit）与 af_fault / mx_fault 分源引线，屏 3 列 2 铺开
```

注意屏 2 的"开 / 关"文字与底色必须由 `ui_fx_mask` 回读刷新，不能长期靠本地缓存（理由见 6.5 的风险一行）。所以第一步的回读通路是屏 2 能上线的前提。

---

## 九、工作量估算

本轮全量回归在跑（`pwsh-1163`），以下全部是估算，本轮一行都没动。

| 阶段 | 内容 | 要动的文件 | 估算 |
|---|---|---|---|
| S0 发送通路（最优先，**最小可用第一步**） | 在 `uart_ui` 内新写回读发送器；`top.v` 接 `tx_busy_i` / `tx_done_i`，把 `tx_start_o` / `tx_data_o` 接进 `u_tx_fifo`；`play_seq` 加 `bpm_cur_o` | `rtl/w3c/uart_ui.v`、`rtl/w3c/play_seq.v`、`rtl/top.v` | 最大的一块。LUT 约 300..600（文本拼装加 30 路 mux），FF 约 100..200。时钟必须走慢使能（1 kHz），不进 50 MHz 关键路径 |
| S1 屏 1 与屏 3 字段 | 21 条 g_sound 内状态引到模块层加进回读表 | `rtl/top.v`（引线）、`uart_ui.v`（表加行） | 中。每条约 5..15 LUT。引线手法照 `led_gear_st` |
| S2 屏 2 链式页（**显示与改值，零协议改动**） | 只加回读表的行（`ui_fx_mask` 已在 S0 的 6 条里）；屏侧做链式图与两类高亮 | `uart_ui.v`（表加行） | 小。屏 2 的**写入与翻转用现有帧**，RTL 侧无新增 |
| S3 EC11 选中参数（**下一轮可选增强**） | `enc_obj_r` 1 位扩到 2 位（必须同步改 `led_indicator.enc_obj_i` 宽度与颜色表）；`enc_tgt_r` / `enc_tgt_o`；`uart_ui` 加 `enc_up_i` / `enc_dn_i`；8 个影子字节寄存器；触摸帧 3..08 | `rtl/top.v`、`rtl/w3c/uart_ui.v`、`rtl/w3a/led_indicator.v` | 中。LUT 约 150..300，FF 约 64 加若干。必须重跑 `tb_uart_ui`、`tb_led_indicator` |
| S4 推子档 2（音量颤音，**下一轮可选增强**） | `fader_gear` 三态切档加 `gear_sel2_i` 加 2 个 12 位输出；`top.v` 在 `fx_chain` 例化处加 2:1 mux 与 12 到 8 位映射；`led_indicator` 注释与标签 | `rtl/w3a/fader_gear.v`、`rtl/top.v`、`rtl/w3a/led_indicator.v`、**`tb/w3a/tb_fader_gear.sv`（判据必改）** | 中。LUT 约 60..120，FF 约 24。**连带成本主要在 tb 判据更新（6 处会红）与一次 PnR** |
| S5 标定页 16 轴快照 | 16 轴 `af*_pol` 快照锁存（否则边刷边变）加 `at_*` / `sp_*` 引线 | `rtl/top.v`、`uart_ui.v` | 中。FF 约 16 乘 12 等于 192 |
| S6 调试页 | 8 个溢出源分源引线（现在取或成 1 bit）；三个计数器与 `ui_hb_ready` 给消费者；编译参数文本 | `rtl/top.v` | 小 |
| S7 屏侧工程 | 建 3 页加常驻状态条，屏 2 的链式图，做字库，定控件 | 新建一套控件清单（`esp32/` 那套是 ESP32 的屏，不适用） | 中。主要是上位机 GUI 工作量，不是 RTL |

**最小可用第一步 = S0**（回读通路 + 6 个零引线字段 + `bpm_cur_o`）。做完 S0 之后屏 1 / 屏 2 / 屏 3 的**显示**就全通，屏 2 的**参数改值与开关翻转**也已可用（它们走现有帧）。S3 / S4 是下一轮可选增强（见 2.2.5）。

汇总：

| 项 | 估算 |
|---|---|
| 最小可用第一步（S0） | 改 3 个文件（`uart_ui` / `play_seq` / `top`），**0 个新模块**，LUT 约 300..600，FF 约 100..200，必须重跑 `tb_uart_ui` / `tb_play_seq` / 全量回归 / PnR |
| 全部做完（含下一轮增强） | 5 个既有模块的改动（`uart_ui` / `play_seq` / `top` / `fader_gear` / `led_indicator`），LUT 约 700..1300，FF 约 330..530 |
| `top.v` 引线 | 约 25..30 条（从 `g_sound` 引到模块层，第二步才做） |
| 时序风险 | 中。本项目当前最差 setup 余量很紧（`top.v:76-79` 记录 Test Mode 扇出锥是瓶颈），所以回读通路必须走慢使能，不进 50 MHz 路径 |
| 必须重跑的验证 | 第一步：`tb_uart_ui`、`tb_play_seq`、全量回归（约 45 分钟）、PnR（约 10 分钟，先 PnR 再回归）。下一轮增强再加 `tb_fader_gear`（判据要先改）、`tb_led_indicator`（若改颜色） |
| 回归风险点（第一步） | 1. `uart_ui` 新增发送器，要保证接收 FSM 逐位不变。2. `play_seq` 加寄存器，要保证三条写路径的限幅语义逐位不变。3. `top.v` 接 `u_tx_fifo` 时注意优先级/交错（见 3.2 的"一次独占 TX 通路"）。4. `top.v` 引线注意 `default_nettype none` 下"声明先于使用"（本项目踩过多次） |
| 回归风险点（下一轮增强） | 5. `enc_obj_r` 扩位必须同步改 `led_indicator` 端口，否则静默截断（`led_indicator.v:108-115` 已记过同一个坑）。6. `fader_gear` 切档从二态变三态，**会让 `tb_fader_gear.sv` 的 6 处判据变红**（见 5.3.4）。7. 8 个影子字节寄存器的换算必须保持"帧落地后 1 拍更新 `fx_*_o`"的既有延迟 |

---

## 十、我没能确认的

| # | 事项 | 为什么没确认 | 建议怎么确认 |
|---|---|---|---|
| 1 | 当前 LUT / FF 余量 | 本轮全量回归在跑，不能跑 PnR 抢 CPU（`AGENTS.md` 第一节"两者别同时开"），无法读最新资源报告 | 回归结束后跑 `sim/gowin_build.ps1`，看 `sim/evidence/` 的资源表 |
| 2 | 屏的 `bauds` 是否支持 500000 | `files/00-总览/对外问询清单.md:76-78` 的 Q7 至今未问未答。已知 ESP32 那块 T1 屏用的是 115200 | 查屏手册或上屏实测（`esp32/串口屏上位机使用说明.md:386-387` 给了官方链接）。这决定 FPGA 侧要不要改 4 处波特率 |
| 3 | `uart_ui` 的 `0x71` 值是否 4 字节小端 | `uart_ui.v:237-240` 自己标注存疑，当前实现只取 1 字节（`val_q`） | 查 TJC 官方手册或上屏实测。对 0..254 的参数值不影响 |
| 4 | 效果器参数在屏上的显示口径 | `gain` 是 Q4.12（字节 64 等于 4.0 倍），`dlylen` 是字节乘 128 采样。显示 ms / 倍率，还是显示原始字节 0..254 | 问用户。建议显示物理量（168 ms、4.0 倍），但 EC11 步长是按字节算的，显示要能反映"一格等于多少" |
| 5 | 8 个影子字节寄存器是否会让 `fx_*_o` 晚 1 拍 | 需要实际改完跑 `tb_uart_ui` 才知道 | 动手时先读 `tb/w3c/tb_uart_ui.sv` 的判据，确认它检查 `fx_*_o` 的时机 |
| 6 | `as_seen` 的准确行号 | `top.v:1802` 只是注释引用，真实声明在 `:3111` 附近，没读到那一行 | `grep -n "as_seen" rtl/top.v` |
| 7 | 音量颤音速率（推子档 2）的缩放系数 | 默认速率是 7，而端口允许 0..255 => 必须缩放，但缩放到多少是听感问题 | 上板听感确定。本文建议 `ch3_i[11:7]` 给 0..31，待确认 |
| 8 | 点 EC11 参数控件时，推子档要不要自动切回档 0 / 1 | 本轮已定"点音量颤音节点 => 推子切档 2"，但反过来（点失真参数 => 推子是否切回）用户没提。本文按"不动"写（两条通路独立），并列出 B / C 两种做法与利弊 | 请用户拍板（见 2.2.3 第 4 条） |
| 8b | 状态条第 5 项"推子档"要不要同时做成可点切档 | 本文建议做成可点（发 `65 13`），这样任何一页都能切档；但会增加一处误触风险 | 请用户确认 |
| 9 | 3 屏是否够 | 我按 1024x600 算：屏 3 有 27 个控件，24 号字可行但偏密 | 请用户拍板。若要屏 3 也用 32 号字，就把 16 轴原始码做成弹出子页，变成 4 屏 |
| 10 | EC11 按压是否改成三态循环 | 取决于是否有 tb 依赖现有"0 与 1 之间循环"的行为。已核 `tb/` 下没有 tb 直接检查 `enc_obj_r` | 按 4.5 推荐先用零回归方案（按压仍是 0 与 1），确认后再考虑增强 |
| 11 | 混响节点是否画进链式图 | 它在 RTL 里是留位直通（`fx_chain.v:300-301`），没有逻辑 | 本文建议画成灰色占位节点（让链看起来完整）；若用户觉得多余可去掉 |
| 12 | 要不要再加"一键全开 / 全关" | 开关翻转走现有 `71 10 <掩码>`（见 6.5），做全开/全关只需屏发一个固定字节（`71 10 07` / `71 10 00`），零 RTL 改动 | 问用户要不要这个按钮。注意它**是绝对写**，会覆盖别人改的位（但对"全开/全关"这种明确意图是合理的） |
| 13 | 节点标题的"开关状态"底色具体取哪几个色 | 我在 2.2.2 的高亮规则表里只写了"整行亮底 / 灰底"，没定具体色值；而它与"选中"的加粗边框 `FFFF00` 要能同时区分 | 上屏试色后定。若颜色在小尺寸控件上不好分，退化成"只留底色明暗 + 文字"，把颜色留给"选中"这一类 |
| 14 | 屏 2 的参数用什么控件改 | 最小可用路径是滑条 / 数字输入 / 加减按钮（走现有 `71 11..18`）；EC11 手拧要等下一轮增强 | 问用户先用哪种。滑条最直观，但 TJC 滑条的分辨率与字节值（0..254）要对齐 |

---

## 附、关联文件

| 想看什么 | 去哪 |
|---|---|
| 屏的现有协议实现 | `rtl/w3c/uart_ui.v`（521 行） |
| 串口命令总表（22 条字母命令） | `rtl/w3a/calib_cmd.v`（762 行，参数定义在 `:89-231`） |
| EC11 接线与对象切换 | `rtl/top.v`（`:707-796`） |
| 推子档位状态机 | `rtl/w3a/fader_gear.v`（270 行，切档在 `:237-242`，语义 mux 在 `:258-266`） |
| 效果器链的级序与使能 | `rtl/w3c/fx_chain.v`（342 行，级序在 `:176-334`） |
| 音量颤音模块 | `rtl/w3c/fx_trem.v`（`DEPTH_W = RATE_W = 8`，默认速率在 `:86`） |
| 指示层（灯等于现有显示） | `rtl/w3a/led_indicator.v`（320 行，档位颜色表在 `:224-229`，位宽静默截断的坑在 `:108-115`） |
| BPM 换算与限幅 | `rtl/w3c/play_seq.v`（`:170-217`） |
| 波特率档位表 | `rtl/w3c/uart_rx.v`（`:26-65`） |
| 诊断回包格式（`'P'` / `'N'` / `'V'`） | `rtl/w3c/pos_probe.v`、`rtl/w3c/span_probe.v` |
| 上行事件帧（14 字节） | `rtl/w3c/evt_upstream.v` |
| TX 队列的"一包一包发"纪律 | `rtl/w3c/uart_tx_fifo.v`（`:116-129`） |
| ESP32 侧已验收的屏实现（字库与踩坑经验可复用） | `esp32/串口屏控件清单.md`、`esp32/evidence/串口屏HMI验收报告-20261001.md` |
| 控制板 16 键映射（第 3 版） | `files/20-代码/控制板16键功能映射-20261013.md` |
| 效果器整合方案（含 2026-10-14 裁定） | `files/20-代码/效果器链-整合方案-20261014.md` |
| 形态决议（屏的定位与尺寸） | `files/30-方案决策/产品形态决议清单.md`（2.4 / 2.8 / 七 / 九） |
