hokuu1102/Gowin2026-PolySynth/files/20-代码/已知问题与风险清单.md

# ⚠️ 已知问题与风险清单（**以后所有问题都往这里放**）

> **本文件位置**：`files/20-代码/已知问题与风险清单.md`
> **约定**：⛔ **不许在别处零零散散记问题** —— 发现任何 RTL / 接口 / 硬件-软件不一致的问题，**一律追加到本文件**，并在"状态"里写明处理到哪一步。
> **配套**：`files/20-代码/代码总览图.md`（现有代码）｜`files/20-代码/W3接口冻结表.md`（接口草案）｜`files/10-硬件/右手板方案.md` §十（板A 冻结件）

---

## 〇、怎么用这份表

| 列 | 含义 |
|---|---|
| **编号** | `K-nn`（K = Known）。⛔ 不要重复用号，追加就往下排 |
| **状态** | `⬜ 待办` ／ `🟡 进行中` ／ `✅ 已解决`（⭐ 解决后**不要删行**，改状态并写上"怎么解决的"） |
| **责任** | 硬件 / RTL / 项目决策 |
| **阻塞什么** | 不解决会导致哪一步做不下去 |

---

## 一、⭐ 阻塞级（不解决就没法正确集成）

> 📌 **编号说明**：编号按**发现顺序**排（越大越晚发现），**分区按严重程度**排。
> 所以本节末尾会出现较大的编号（`K-28`~`K-33`）—— 那是后追加进来的阻塞项，**不是排序错误**。

| 编号 | 问题 | 依据 / 现象 | 责任 | 阻塞什么 | 状态 |
|---|---|---|---|---|---|
| **K-01** | ✅ **`TLC5916` 的 `OE_n` 安全门控** —— ~~现有驱动每个系统周期直接寄存 `outputs_enable` 到 `OE_n`，**单周期误脉冲无法被阻止**~~ | `OE` 上出现"**一个 CLK 宽的窄脉冲**"会进 Special Mode（TI **SLVS695D §9.4.1**：触发条件是"**OE 低电平恰好跨过 1 个 CLK 上升沿**"，⛔ 不是某个 ns 宽度），此后输出不再受 `SDI`/`LE` 控制 —— 现象是"明明在移位，灯就是不亮/乱亮"，**只能断电恢复** | RTL | LED 集成、现场演示稳定性 | ✅ **已修（2026-09-17）**：加**双重结构性防护** —— ① `OE` 稳定窗（`OE_STABLE=8` 拍，滤掉毛刺）② **只在"CLK 静止 + `LE` 低 + 不在传输"时才更新 `OE`** ⇒ "跨过 1 个 CLK 上升沿"在结构上不可能。⭐ 用例：1 拍窄脉冲被完全滤掉、传输期间 `OE` 不动（`tb/drivers/tb_tlc5916_driver.sv`）。⛔ 待办：把 TI 官方的「1-CLK 宽 OE 脉冲 + LE 低」**恢复序列**做进上电自检（把致命故障降级为可自愈） |
| **K-02** | ✅ **`OE` 是低有效** | 手册：`OE(ED2)` 低 = 输出使能；高 = 全部关断。内部自带 **500 kΩ 上拉** ⇒ 悬空即灭 | RTL | LED 全不亮 | ✅ **已确认并落地**：驱动复位值 `tlc_oe_n=1`（关断），`.cst` 侧将来给 `OE` 明确 `PULL_MODE=UP` |
| **K-03** | ✅ **`LE` 必须在移位期间保持低** | `LE` 是电平有效锁存；全程拉高会让输出跟着移位寄存器抖，且**模式切换阶段靠 `LE` 电平决定去留** | RTL | LED 乱亮 | ✅ **已修（2026-09-17）**：原来 `LE` 抬高的**同一拍** `tlc_clk` 还在 1→0 跳变（**LE 高时出现 CLK 边沿**）⇒ 新增 `STATE_LE_WAIT`：先拉低 CLK、**下一拍**再抬 `LE`（代价 1 拍）。⭐ `A2` 检查器（`chk_le_shift`）已接到该 tb，现为 **0 违规** |
| **K-04** | ✅ **`W3接口冻结表.md` 已过时** —— 原只有单个 8 bit `vibrato`、速率写死 5–6 Hz、**结构体里残留已作废的 `pitch_fine[11:0]`** | 最新硬件：推子1 = 颤音**深度**、推子2 = 颤音**速率 1–12 Hz**、另有**数字主音量** | RTL + 文档 | 控制前端无法冻结 | ✅ **已解决（2026-09-16）**：结构体改为 `vibrato_depth`+`vibrato_rate`+`master_volume`+`timbre`，删除 `pitch_fine`，正文"固定 5~6 Hz"改为推子控制 |
| **K-05** | ✅ **`代码总览图.md` 写着"共用 SCLK/MOSI/MISO，靠 CS1/CS2/CS3 区分"** | 真实硬件是**每板各自一条排线、各自一组四线** ⇒ `MISO` 必须是**独立 FPGA 输入** | RTL + 文档 | ADC 采集链接口 | ⭐ **部分解决（2026-09-16）**：`代码总览图.md` 已改为"各自四线 / `MISO` 独立"、`chan_scan` 口径同步为帧 `0.5 ms`；⚠️ **但 `files/历史/采集链参数复核-过时-旧共享总线口径.md` / `files/历史/延迟预算逐段分解-过时-旧共享总线口径.md` 还没改 → 见 K-31** |
| **K-06** | ⚠️ **每片 ADC 的 `MISO` 必须独立**，⛔ 不能把多片 `MISO` 直接并到一个 FPGA 输入 | 未选中器件的 `DOUT` 是否可靠高阻**没有板级证据**；⛔ `74HC165` 更没有三态语义（见 K-12） | RTL + 硬件 | ADC 采集链 | ⬜ 待办 |
| **K-28** | ⛔⛔ **两份已入库的架构文档"波表 ROM 能否共享"直接矛盾** | ⭐ `合成引擎架构决策.md` §2.1：**"波表 ROM 可以共享"**（2026-09-17 已补判据澄清）；⚠️ `RTL代码结构与接口规划.md` §0.1：**"默认每 lane 一块 18 Kbit BSRAM …… 若不能证明未合并，则不按 N 个波表振荡器申报"** | 项目决策 | ⭐ 振荡器数申报口径 / BSRAM 预算 / 平台选型（60K 还是 138K） | 🟡 **已按评分规则原文裁决（2026-09-17）**：规则 §3.1 的判据是「独立**相位累加器** + **频率调控** + **包络控制**」，**ROM 不在判据内** ⇒ **共享 ROM 不影响计数**。⇒ ⭐ **不再阻塞开工**：资源按共享口径算（`files/20-代码/FPGA平台与资源评估.md` ≈1014 kb / 48 %），⛔ 不为"凑未合并的证据"付每 lane 一块 ROM 的代价（64 块 ≈ 60K 的 54 %，会挤掉混响）。⚠️ 规则那句「仅计单个振荡器」可被反向解读 ⇒ **仍需主办方书面答复留痕**（见 `files/00-总览/第一周/分工.md` A1）<br>⭐⭐ **2026-09-19 已问到主办方（口头答复，原话）**：「**无法具体断定，建议详细阅读赛题并且根据自己实际设计确定。最终应该还是比较注重于整体效果；是否合规应该是说得通即可，但是评分肯定得看效果了。**」⇒ ⭐ **读法**：①「无法具体断定」= **没有机械判据，是人工判断**；②「说得通即可」= ⭐⭐ **合规的关键是"能自圆其说" ⇒ 证据链必须完整**；③「评分看效果」= ⭐ **数量做不上去，合规再漂亮也没分**。⇒ **结论：合规上"讲得清"就行，分是靠"数量 + 效果"挣的**；⛔ 别指望一条硬规则保底 |
| **K-84** | ⭐⭐ **用厂商 DDS IP 生成 N 路正弦，"算不算 N 个独立振荡器"**（2026-09-19 提问） | 判据仍取规则 §3.1 的**三条**（独立相位累加器 + 频率调控 + 包络控制）：<br>· ⭐ **例化 N 个 DDS IP**（各自独立 `FREQ_CTRL`）⇒ ✅ **算 N 个**（DDS 的定义就是"相位累加器 + 相幅转换"，每个实例内含**一个**独立相位累加器）；<br>· ⛔ **1 个 DDS IP 内部 TDM 分时复用** ⇒ ⚠️ **只算 1 个**（共用相位累加器 ⇒ 不满足"独立"）；<br>· ⚠️ **包络不在 DDS IP 里** ⇒ **必须给每路配独立 ADSR**，否则按"三条缺一"**说不成完整振荡器**。<br>⚠️⚠️ **三个真风险**：① ⭐ **黑盒 ⇒ 规则 §3.3 要的"RTL 代码佐证"给不出**（相位累加器在 IP 内部，评委翻代码只看到一行例化；若 IP 是加密网表更说不清）；② IP 核口径本身是灰区（`K-40`，未问官方）；③ **4 路对分数几乎没帮助**（吞吐量 = N × fs；4 路只比基础要求高一点，拿不到"≥32"那一项）。<br>📌 另注：规则「**过采样不叠加加分**」⇒ ⛔ **"TDM 抬采样率假造 N 路"这条路被直接堵死**<br>🔴 **编号更正（2026-09-20）**：本条**原为 `K-80`**，与采集线新落的 `K-80`（A4/A5 口径裁决，2026-09-20）**撞号** ⇒ ⭐ 本条改为 **`K-84`**（撞号原因：两条线并行推进、各自按当时最大号 +1）。 | 架构选型/合规 | ⭐ 振荡器申报口径、`K-40`、交付架构 | ⚠️ **2026-09-20 定量复核后更新（见 `K-83`）**：⭐ **资源上"64 个 DDS IP"几乎不可行**（每实例自带 ROM 且**加密不可合并** ⇒ 最省配置也要吃掉 **97 % BSRAM**）。⇒ **结论从"建议自己写"升级为"必须自己写"**。⭐ 自己写只要 **131 kbit**（4 音色 × 2 表 × 1024 点 × 16 bit，**全设计共享**），且相位累加器只有 **`phase <= phase + phase_inc` 一行**<br>⭐⭐ **2026-09-20 实测印证**：乙已落地的 `rtl/w3b/dds_wavetable_core.v` **正是自己写相位累加器**（`phase_acc <= phase_acc + phase_inc_i`）+ **共享一块 pROM** ⇒ ⭐ **与本条结论一致，且已过 M1 真链路验收** |
| **K-83** | 🔴⭐ **Gowin DDS IP 每实例自带 ROM 且【加密不可合并】⇒ 64 实例会吃掉 97 % BSRAM**（2026-09-20 定量复核） | **背景**：曾倾向"允许用 IP 就用 IP"（省事、避免自己写错）⇒ 按 BSRAM 实算了一遍。<br>**事实**：Gowin DDS IP 的相幅转换是**内部 ROM 查表**（用户指南：正弦 `addr = (1'b0, C_PHASE_ANGLE_WIDTH[P-1:0])` ⇒ **ROM 深度 = 2^P**，`P` = 相位角度位宽）。⚠️ 且 **Gowin IP 是加密网表** ⇒ ⛔ **综合器无法把 64 个实例的 ROM 合并成一份**。<br>**算账**（`POLY_TARGET=32` × `OSC_PER_VOICE=2` = **64 个振荡器**；基线 = 其它模块 883 kb + looper 393 kb）：<br>· P=10 / W=12 ⇒ 每实例 12.3 kb ⇒ 64 实例 **786 kb** ⇒ 总计 **2 062 kb = 97.1 %** ⚠️ **几乎没余量**<br>· P=10 / W=16 ⇒ **1 049 kb** ⇒ 总计 **2 325 kb = 109 %** 🔴 **放不下**<br>· P=12 / W=16 ⇒ **4 194 kb** ⇒ 总计 **5 470 kb = 258 %** 🔴 **远超**<br>**对照**：⭐ **自己写 = 131 kbit**（共享波表）⇒ 总计 **1 407 kb = 66 %** ✅ **有余量** | 架构选型/资源 | 🔴 **振荡器实现方式（决定整个合成核心怎么写）** | ✅ **结论：自己写相位累加器 + 共享波表**。⭐ **三条理由**：① ⚠️ **资源**（IP 最省配置 97 % vs 自己写 66 %）；② ⭐ **合规**（`K-84`：加密网表**给不出**规则 §3.3 要的"RTL 代码佐证"，而**评委要翻代码**）；③ ⭐ **成本极低**（相位累加器**就一行** `phase <= phase + phase_inc`）。<br>⭐⭐ **2026-09-20 实测印证：本条已由队友落地实现** —— `rtl/w3b/dds_wavetable_core.v` **正是自己写 32-bit 相位累加器**（`phase_acc <= phase_acc + phase_inc_i`，改 `phase_inc` 不复位）+ **`wavetable_bank.v` 共享一块 Gowin pROM**（`ip/wavetable_sine_rom_ip/`，512×16 ⇒ 综合 **1 BSRAM**），并已过 M1 真链路（1032/1032 逐点一致、SNR 125.41 dB）。⚠️ **注意区分**：这里用的是 **pROM（只读波表 ROM）**，⛔ **不是 DDS IP** —— 前者只提供"查表"，相位累加器仍是自己写的 RTL ⇒ **完全符合本条结论** |
| **K-29** | ✅ **Test Mode 档位两套口径** | 统一为：必做 `4/8/16/32`，`64` 留参数与端口扩展位、不实现。依据：规则原文只要求"多路不同频率 + 谱峰可数"，**未规定 N**；`4` 守基础题复音 ≥4、`32` 守拓展题 ≥32，`64` 无任何依据 | RTL + 文档 | 验收范围、资源 | ✅ **已解决（2026-09-17）**：`合成引擎架构决策.md` §三 / §四 的两处 `4/8/16/32/64` 已改为 `4/8/16/32`（`64` 只留参数位） |
| **K-30** | ✅ **FM 计数口径措辞不一** | ⭐ 统一为**两句话各管一个口径**：**「FM 按调制运算器统计」= 只用于"FM 合成"评分项**；**「FM 调制器 ⛔ 不计入吞吐量」= 打分公式不含它**（主办方口径见 `合成引擎架构决策.md` §7.3） | RTL + 文档 | 吞吐量申报 | ✅ **已解决（2026-09-17）**：`合成引擎架构决策.md` §一 / §2.3 / §三 / §7.5(A2-3) 四处"计数双收益"措辞已统一为"**只有音色收益、不计入吞吐量**"；`FM_OPS` 统一为现 **0** 预留、上限 **0~4**（见 K-36） |
| **K-31** | ⚠️ **`files/历史/采集链参数复核-过时-旧共享总线口径.md` 与 `files/历史/延迟预算逐段分解-过时-旧共享总线口径.md` 仍按"24 通道共享一条 SPI 总线 / 2 kHz 每通道"估算** | 与 K-05 同一根源。⇒ 必须按 **3 组独立四线 + `1 kΩ+10 nF` 模拟 RC + 整片帧 `0.5 ms`** 重算端到端延迟预算（ADC 侧 ≤0.5 ms） | RTL + 文档 | 延迟论证、"≤5 ms 确定性" | ✅ **已解决（2026-09-22）**：⭐ 已按 **3 组独立四线 + `1 kΩ+10 nF` + 整片帧 `0.5 ms`** 重算<br>⭐ 新文档：`files/20-代码/延迟预算逐段分解.md`（现行口径）<br>⭐ 结论：**最坏 563.6 µs**、**平均 293.1 µs** ⇒ 对 5 ms 余量 **8.87 倍**；⭐ **八段全确定性**<br>⚠️ 凡与旧文档冲突一概以新文档为准 |
| **K-32** | ⭐ **多片 `TLC5916` 的时钟/锁存分组**：左手两板各 1 片、板 B 1 片（共 3 片） | **已确认的硬件事实**：各片 `SDI` **独立**；`LED_CLK` / `LE` / `OE` **可以共用**（并联广播），但 ⛔ **灯的移位 `CLK` 与 ADC 的 SPI `SCK` 不是同一条**（K-13）。⇒ RTL 顶层需要明确的端口分组：`SDI×3` + 共用 `CLK/LE/OE_n`（或按板分开，选一种并写死） | RTL + 硬件 | TLC 顶层端口冻结 | ⬜ **待冻结** —— ⚠️ 2026-09-17 补充：`RTL代码结构与接口规划.md` 已**单方面写死三组独立**（`tlc_clk_o[2:0]` / `tlc_le_o[2:0]` / `tlc_oe_n_o[2:0]` = 9 根引脚），属"未冻结即实现"；冻结时须**二选一写死**（若共用可省 6 根引脚） |
| **K-33** | ⚠️ **板 B 原理图尚未画** —— K-14（OLED SPI mode）、K-15（双色灯到 `OUT0~7` 的颜色映射）、K-26（显示口径）全部挂在它上面 | 板 B 画完前，OLED / 按键 / 双色灯的顶层端口无法冻结 | 硬件 | 人机接口冻结 | ⬜ **待办 —— 已排期：国庆（10/1–10/7）做**（等 FPGA 与 PCB 到手、与 3D 建模同批）。⚠️ 同期顺延的还有 **P1 拓展板**；⚠️ **打样厂国庆停** ⇒ 节后才投板、约 10/13–10/14 回板，**与"10/14 整机能弹"直接冲突**<br>🔴 **2026-09-30 计划变更（⭐ 用户决定，⛔ 原计划保留在上方）**：⭐ **板 B 改为【通用控制板】**（⭐ 可能做**矩阵键盘**，**键数与接口待定**）⇒ ⭐ **本次不分配任何引脚**（⭐ 早先分的 10 根**已撤回**）；🔴 **`OLED` 已取消** ⇒ ⭐ 挂在它上面的 **`K-14` 随之作废**（⭐ 保留痕迹）；⚠️ **`K-15`（双色灯映射）/ `K-26`（显示口径）仍取决于板 B 的最终形态** ⇒ ⭐ **画板前必须先定"键数与接口"**（⭐ 见 `files/10-硬件/右手板方案.md` §二 与 `bringup/17-引脚分配-左手板2与右手板-20260930.md` §四） |
| **K-34** | ⛔ **被指定为"M0~M8 验收依据"的 `files/20-代码/RTL代码结构与接口规划.md` 里，有 3 条已被推翻的结论仍在正文生效**：① 同一通道 **`250_000` 周期（5.000 ms）** 重访；② 三片 ADC **共享一条 SPI 总线**；③ 仍在设计 **`74HC165`** 按键并串 | ① 与 `K-07`（RC 已统一 `1 kΩ+10 nF` ⇒ **`25_000` 周期 / 0.5 ms**）直接矛盾，且该文自称"旧的 0.5 ms 口径已失效"**方向反了**；② 与 `K-05`/`K-06` 矛盾；③ 与 `K-12`（⛔ 不用 165、按键直连）矛盾 | 文档 + 队友 | ⛔ **采集链（丙）不得按该文的 `ADC_REVISIT_CYC = 250_000` 写代码**（应为 `25_000`）；`M3` 验收口径 | ⬜ **待办** —— ⚠️ 该文档属"队友的两份文档不动"范围（`files/00-总览/第一周/README.md` §附），**须经其作者同意后再改** |

---

## 二、⭐ 口径必须统一（否则两个人写出两套数）

| 编号 | 问题 | 正确的口径 | 责任 | 状态 |
|---|---|---|---|---|
| **K-07** | ✅ **ADC 采样周期口径已统一** —— 旧文档按 `10 kΩ+100 nF` 推出"每通道 ≥5 ms"，与"控制→出声 ≤5 ms"直接打架 | 硬件已统一为 **`1 kΩ + 10 nF`**（τ=10 µs、fc≈16 kHz）⇒ **同一通道重访 ≥50 µs 即可**；建议**整片帧周期 `0.5 ms`（每通道 2 kHz）**。⭐ `MCP3208` @3.3 V / 1 MHz SCK 整片 8 通道扫完 ≈ **150 µs** ⇒ 芯片完全支撑 | RTL | ✅ 已解决（见 `files/10-硬件/右手板方案.md` §10.2） |
| **K-08** | ⭐ **低延迟论证的硬件前提**：`UP`/`DOWN` 的"<5 ms 可证明"**只在比较器接在 RC 之前（`PICK`）时成立** | 接在 `CH0`（RC 之后）会引入 1~3 ms 且**随动作速度变化**（破坏确定性） | 硬件 + RTL | ✅ 已明确（写进 `files/10-硬件/右手板方案.md` §10.2 第 1 条） |
| **K-09** | ⭐ **`B10K` 音量是线性电位器 ⇒ 位置→增益必须套对数映射**（32~64 点查表） | 不套：前段一转就爆音、后段转半圈没变化。**曲线放固件里，不要靠换电位器** | RTL | ✅ **RTL 完成（T17，2026-09-26）**：`right_analog_ctrl` 将 P4 ADC CH1 高 6 bit 送入 64 点 LUT（0=硬静音，1..63 为 −60 dB..0 dB 的等 dB 步进），输出 Q1.15 增益到 `master_mix`；后者继续以 sample tick 斜坡平滑过渡。`tb_right_analog_ctrl` 已遍历验证单调性/端点，`tb_vibrato_top` 验证 P4 启用与禁用（禁用保持 unity）均正确。⬜ **仍待 P4 实物接线后的听感曲线确认**。 |
| **K-10** | ✅ **变调只改 `phase_inc`，⛔ 绝不清零 `phase_acc`** | 清零相位 = 波形跳变 = **咔哒声** | RTL | ✅ **已解决并验收（2026-09-20）**：`voice` 运行中只更新 `phase_inc`；`tb_pitch_shift_accept` 在非零相位持音变调，`A7=0`、golden 616/616、I2S 0 错，前后 FFT 均为单峰。临时注入清零缺陷时 `A7=1` 且测试失败。⚠️ 上板听感/示波器确认待板卡到货 |
| **K-11** | ⚠️ **颤音深度要死区+迟滞、速率要斜率限制** | 深度在阈值附近抖动 → 颤音断续；速率直接跳变 → 听到**音高跳变** | RTL | ✅ **RTL 完成（T18，2026-09-26）**：`vibrato_lfo` 以 OFF=64 / ON=96 双阈值消除端点抖动；CH3 速率映射 1~12 Hz，控制快照每 5 ms 最大仅变 16 个 phase-inc LSB；相位永不因参数更新清零。`tb_vibrato_lfo`、`tb_right_analog_ctrl`、`tb_vibrato_top` 均通过。⬜ **仍待 P4 实物接线后上板听感确认**（构建时设 `RIGHT_ADC_ENABLE=1`）。 |
| **K-35** | ⚠️ **音色 / 波表规格三份现行文档不一致** | `合成引擎架构决策.md` §7.5 写 **4 音色 × 2048 点**（`files/20-代码/FPGA平台与资源评估.md` §三之二 同，131 kb）；`RTL代码结构与接口规划.md` §0.1 写 **2 音色 × 512 点**；`files/20-代码/音色设计.md` §3.2 写 **2 音色（T1/T2，各 soft/hard 共 4 表）× 1024 点 × 16 bit = 64 kbit** | RTL（乙）+ 文档 | 波表 ROM 规格与 BSRAM 预算 | ⭐ **建议以 `files/20-代码/音色设计.md` 为准**（它是唯一的音色权威，`files/00-总览/规划待办清单.md` A4 标"配方已定"）→ 待乙确认后同步另两份<br>✅ **代码裁定**：⭐ **4 音色 × 1024 点 × soft/hard**（`wavetable_bank.v` 的 `TIMBRE_N`/`TIMBRE_W`/`DEPTH`）⇒ ⭐ **"2 音色"口径作废** |
| **K-36** | ⚠️ **FM 算子数两套口径** | `合成引擎架构决策.md` §7.6 写"**4~6 OP 比较完整**"（§7.7 与 `files/00-总览/规划待办清单.md` A2c 同），同文 §7.5 定案表与 `RTL代码结构与接口规划.md` 参数表写 **`FM_OPS = 0`（0~4）** | RTL（乙）+ 文档 | 对外材料口径唯一性 | 🟡 **已按 §7.5 定案表口径统一（2026-09-17）**：`FM_OPS` 现为 **0**（只留接口）、上限 **0~4**；`4~6 OP` 降级为"将来做 FM 时"的经验值参考（见 A2-3 行）|
| **K-37** | ⚠️ **左手区尺寸链旧值（`15 mm` / `105 mm` / `~60 mm`）仍散落在多份现行文档**，且 `files/10-硬件/硬件接口总表.md` 的自查行曾与它自己正文的 `140 mm` 直接打架 | 新口径（2026-09-13）：列间距 **20 mm**、跨缝 **20 mm**、对称留边**各 10 mm**、8 列轴心跨距 **140 mm**、板宽 **~100 mm** | 硬件 A | ⚠️ **投板后改不了**；牵动定位板/键帽/外壳建模与映射表 | 🟡 **部分解决（2026-09-17）**：`硬件接口总表.md` 的自查行已改为 140 mm 口径；⚠️ 其余旧值仍待硬件 A 按 `files/00-总览/规划待办清单.md` C12 批量重算（涉及 `当前方案总览` / `硬件选型表` / `项目时间线` / `机械与硬件待做任务表` / `板子划分与板间接口` / `采购与验证清单` 等） |

---

## 三、采集与人机接口

| 编号 | 问题 | 说明 | 责任 | 状态 |
|---|---|---|---|---|
| **K-12** | ⭐ **不用 `74HC165`** —— 每板按键**直连 FPGA 引脚** | 165 的 `QH` **没有三态/输出使能**，若与 ADC 的 `MISO` 硬并会抢线；既然不用它，就直连，代价是多几个引脚 | 硬件 + RTL | ✅ 已定（板B 不用 165） |
| **K-13** | ⭐ **灯的 `CLK` 与输入的 `SCK` 不是同一条** | `TLC5916` 的移位时钟 与 `MCP3208` 的 SPI `SCK` **各自独立**，⛔ 不要因为"都是移位"就复用 | 硬件 + RTL | ✅ 已明确 |
| **K-14** | `OLED` = **SSD1306 / SPI**，信号 `D0(SCLK) / D1(MOSI) / RES / DC / CS` | ⚠️ 需确认：是否需要独立 `RST`、SPI mode（SSD1306 SPI 通常 **Mode 0/3**，且**只写不读**） | 硬件 + RTL | 🔴 **已作废（2026-09-30）**：⭐ **`OLED` 已取消**（⭐ 用户决定，⭐ 板 B 改为**通用控制板**、可能做矩阵键盘）⇒ ⭐ **本条不再需要确认**；⛔ **保留痕迹** —— ⚠️ 若将来重启显示方案再恢复本条。📌 关联 `K-33` |
| **K-15** | **双色 LED 共阳极** ⇒ `TLC5916` 灌电流正好匹配（阳极接 `3V3`，每色一路 sink） | `R_EXT = 4.7 kΩ` → 约 4 mA/路；⛔ 不做 PWM 调光 | 硬件 | ✅ 已明确 |
| **K-16** | **`MCP3208` 的 `VCC` 与 `VREF` 都接 `3V3`** ⇒ 比例式测量（与霍尔/电位器激励同源） | 电源波动同时作用于传感器与参考 ⇒ 大部分抵消 | 硬件 + RTL | ✅ 已明确 |
| **K-17** | ⭐ **通道编号以 `files/10-硬件/` 下的硬件文档为准** | 左右手板各有一份通道表；RTL 的通道索引**必须照抄**，⛔ 不要自己按物理顺序假设 | RTL | ⬜ 待办（写 RTL 时对照） |

---

## 四、项目决策（需人拍板，已定 / 待定）

| 编号 | 事项 | 结论 | 状态 |
|---|---|---|---|
| **K-18** | ⭐⭐ **演奏语义** | **键盘模式：轴过阈值即响（自动 Note On）**；**指板模式：先选轴，拨弦（`UP`/`DOWN` 事件）才响** | ✅ 已定 |
| **K-19** | ⭐ **`UP` 与 `DOWN` 同时有效** | **优先 `UP`** | ✅ 已定 |
| **K-20** | **复位源** | **用开发板上的复位按钮** → ⭐ **引脚已确认：`AA13`**（`LVCMOS15` / `PULL_UP`），来自官方 60K `.cst`。⚠️ 原候选 `Y12` 是 **`Key_in[1]` 按键**，不是复位 | ✅ **已解决（2026-09-17）** |
| **K-21** | **测试模式档位** | ⭐ **按题目最低限度要求：`4/8/16/32` 四档必做**；**预留提高的接口与空间**（不实现 `64`，但参数与端口留出扩展位） | ✅ 已定 |
| **K-22** | **Dock 准确型号 / 速度等级 / 非音频信号 ball 映射** | ⭐ **已确认（2026-09-17）**：板卡 = **`Tang Mega 60K`**，核心板器件 = **`GW5AT-LV60PG484AC1/I0`**，底板 = **`TANG MEGA NEO`**；⭐ **60K 与 138K 共用同一套底板 ⇒ 外设完全相同**（Sipeed wiki 原文）。非音频 ball 映射见官方 `tang_mega_60K_pins.cst`（本地在 files/开发板原理图/ ，该目录被 gitignore、⛔ 不入库） | ✅ **已解决** |
| **K-23** | ⭐ **系统时钟脚** | ⭐ **已确认：`V22` / `LVCMOS33`**（官方 60K `.cst` 里就叫 `sys_clk`）；⛔ 不能沿用旧基石板的 `F13`；`AB12` 是 MS5351 可编程时钟输入（我们⛔ 不用） | ✅ **已解决（2026-09-17）** |
| **K-24** | **板载 DAC 型号 / I2S 格式 / LRCK 极性 / 是否需要物理 MCLK** | ⭐ **已确认（2026-09-17）**：DAC = **`PT8211-S`**（Princeton，**16 bit** 立体声 I2S DAC；功放 `NS4263`）；**LSBJ（日本格式 = 右对齐）**：16 bit 数据放在**时隙尾部**、**MSB 先出**；⚠️ `HP_WS` 极性两份参考实现矛盾（我们**单声道** ⇒ 无影响，参数 `LRCK_POL` 可切）；**每声道 16 bit**；**⛔ 不需要物理 MCLK**；**`PA_EN` 低有效**（`PA_EN=0` ⇒ PA 开）。依据：Dock 原理图元件表 + 官方例程 `audio_drive.v`（github.com/sipeed/TangMega-138K-example → audio_i2s） | ✅ **已解决** → 见 `files/10-硬件/开发板与引脚资料.md` §9.1.1 |
| **K-39** | ✅ **BCK 频率 / 帧结构口径** | ⭐ **已结案（2026-09-17）**：PT8211 = **LSBJ 右对齐**。依据 ①规格书正文「LSBJ / Japanese input format … MSB first」；②一份**已验证出声**的驱动 `LSBJ_audio_driver.v`（立创逻辑派）：每声道时隙 **24 BCK**、数据只占**后 16 个 BCK**、MSB 先出、且时隙里**还有 8 个空闲 BCK** ⇒ ①确认右对齐 ②**DAC 容许时隙里多出 BCK** | RTL | ⭐ I2S 上板能否出声 | ✅ **已解决**：沿用冻结的 `BCLK = 3.125 MHz = 64 × fs`（每声道 32 BCK），数据**右对齐**即可，⛔ `M0` 的数字不用改；`i2s_tx` 的 `JUSTIFY=1` 为默认 |
| **K-40** | ✅ **厂商 IP 核 / 软核 / MCU 的使用口径 —— 已问主办方并拿到明确答复**（2026-09-19） | 赛题原文只说「完整音频通路**全部基于 HDL**……**杜绝软件串行**」，**没有「IP 核」这个措辞**。<br>⭐⭐ **主办方答复（原话要点）**：<br>① 使用 **MCU** 的部分**可能不会计入工作量**（成品或自制都一样）；<br>② 只要**不是绝大部分功能**都用软核/MCU，**就不会导致弃赛**；<br>③ ⭐⭐ **选题二的「音频」与「视觉效果」部分绝对不要用软核/MCU**，否则可能不计入工作量；<br>④ ⭐⭐⭐ **关键定义**：「软核」指**通用 CPU/MCU 软核**（如 M1 软核，**俗话说的"跑 C 语言那种"**）；⭐ **为具体算法需求专门设计的【状态机】或【串行架构的算法加速器】不是软核** —— 「这体现了 FPGA 的不可替代性」；⚠️ **内置 RISC-V CPU 硬核**也**类似软核**；<br>⑤ 「不计入工作量」的**准确含义**：⛔ **不是从总分扣分**，而是**对该部分功能的设计与实现得分造成间接影响**；⭐ 且**不会因为 1% 用了 MCU 就整个模块清零**（剩余 99% 照算）；若评委认为用得合理，**可能打折或正常计入**；<br>⑥ ⚠️ **要考虑对实时性的影响** —— 今年三道题对实时性要求都高 | RTL + 文档 | ⭐ 架构选型、对外申报 | ✅ **已解决（口径明确）**。⭐⭐ **对我们的结论**：<br>· ✅ **我们没踩线** —— 全设计**无软核、无 MCU、无硬核**；且**所有外设驱动都是"专用状态机"**（`tlc5916_driver` / `mcp3208_driver` / `i2s_tx`）⇒ 按新口径**这些明确不是软核**，**全额计入工作量**；<br>· ⚠️ **一处口径要改**：旧文写「CPU 做 **UI 渲染** ✅ 合规」—— 新答复把**视觉效果**划进禁区，须复核（见 `K-81`）；<br>· ⭐ **答辩话术升级**：不只说"没用 CPU"，还要说"**我们的驱动是专用状态机，不是通用 CPU**"；<br>· 📌 与我们更严的自有约定不冲突（⛔ 不用 PLL） |
| **K-81** | ⚠️ **"视觉效果"被划进软核禁区 —— 我们的可视化方案要复核**（2026-09-19 据主办方答复） | 主办方明确「**选题二的音频、视觉效果部分绝对不要用软核/MCU**」。⚠️ 而赛题拓展要求 3 原文是「**基于 FPGA 硬件逻辑实时生成可视化反馈**，包含 LED 演奏指引、**李萨如图形、实时频谱、波形显示**」。⇒ 我们的可视化方案有两处**需复核**：<br>① ⚠️ **串口屏（TJC X2 自带 MCU 渲染）** —— 若"波形/频谱"是**屏自己画的**，是否还算"FPGA 逻辑生成可视化"？（⚠️ 旧文 `产品形态决议清单.md` 曾写"X2 **自带曲线波形控件**，屏能自己画波形"）<br>② ⚠️ **旧口径**「CPU 做 UI 渲染 ✅ 合规」（`FPGA平台与资源评估.md` §5.2）与本次答复**直接冲突** | 架构选型/合规 | ⭐ 拓展要求 3 的得分（"实时视听反馈"是**独立评分项**） | ⬜ **待复核 + 待确认**：<br>· ⭐ **安全做法**：**可视化的"生成"必须在 FPGA 内完成**（`vis_tap` 输出**已算好的波形/频谱点**），串口屏/HDMI 只做**搬运与显示**，⛔ 不让屏承担"生成"；<br>· ⭐ 这也**正好符合我们已定的架构**（`vis_tap.v` = "可视化数据出口"，波形/频谱/李萨如都由 FPGA 算）；<br>· ⚠️ **要写进答辩话术与视频**：「频谱/波形点由 FPGA 实时算出，屏只显示」；<br>· ❓ 若时间允许，**顺带问主办方**"外接自带 MCU 的显示模块算不算" |
| **K-41** | ⭐ **PLL 口径**：文档多处写「⛔ 不用 PLL」，准确边界是「**⛔ 不用 PLL 输出做全设计系统时钟**」 | 依据上一个项目 `ADDA` 的实测（经验库 `L31`）：逻辑全搬到 PLL 域后，`clk50` 只驱动 mdclk ⇒ 被工具**降级**（`WARN PR1014`）+ `PLL_INIT` 等 `I_LOCK` ⇒ **PLL 从未释放、全设计无时钟**（综合/布线**零 error**）。⚠️ 另有两条**独立**坑常被混为一谈：① `.ipc` 声明输入 100 MHz 而实物 50 MHz ⇒ 输出静默减半，且 **fVCO 仅 350 MHz = 手册下限 700 MHz 的一半**（越规格，`T57`/`U34`）；② 直读异域寄存器亚稳（`L28`，是 CDC 问题）。⚠️ **补充（2026-09-17）**：那次 `PR1014` 只是**同时出现的现象**，⛔ 它本身**不等于**"板子坏了"：我们现在这个**没有 PLL** 的设计**每次构建都会出 `PR1014`**（成因 = 板载时钟脚 `V22` 不是专用时钟脚），而时序完全正常（见 `K-45`）。⇒ 以后看到它，先看"**时钟上没上全局主干 + 违规端点是不是 0**"。✅ PLL 用于**外设 / 相移时钟**是正常的（官方音频例程也用 `PLL + CLKDIV`） | RTL + 文档 | 时钟架构；将来若要改 `fs` | ✅ **口径已明确**：我们 `50 MHz ÷ 1024 = 48828.125 Hz` **整数可分 ⇒ 本设计不需要 PLL**；若将来真要用：⛔ 不得做系统时钟 + **必须留「活体见证」**（UART/心跳仍跑板载时钟）；验证方法 = 4 步实验（双活体见证 + 三份构建报告 + 按手册算 fVCO + 对照实验），见经验库 `L31` 补充 |
| **K-25** | **串口屏 `TJC X2` 的串口电平与 baud** | ⏳ 待查（决定要不要电平转换） | ⬜ 待定 |
| **K-26** | **十六进制/显示口径**：`0.96″ OLED` 显示哪些状态、双色灯 4 灯的状态编码 | `files/10-硬件/右手板方案.md` §二 已给建议编码，待最终确认 | ⬜ 待定 |
| **K-42** | 🔴 **`PA_EN` 在上电 / FPGA 配置期间的安全态**（⚠️ **换板后语义已变**，见下） | 我们的复位约定是**同步复位**（`W3接口冻结表.md` §〇 约定 2）⇒ **上电到第一个时钟沿之间，寄存器的值是未定义的**。对"必须一上电就安全"的脚（功放使能、`OE` 等），**仿真里"复位生效后 = 1"并不等于"上电期间 = 1"**。⭐ 解法 = **引脚上拉**：`constr/top.cst` 里给 `PA_EN_n` 设 `PULL_MODE=UP` ⇒ **配置期间被拉高 = 功放关断**（官方例程同样这么做，⛔ 不是我们的新发明） | RTL + `constr/top.cst` | 上电"啪"声 / 不确定状态；⛔ 别指望 `initial` 或复位 | ✅ **已修**（⭐ 2026-09-30 回填；⭐ 原标 **🔴🔴 换板后【已变化】(2026-09-22)** —— 原文记录保留）：⭐ `PA_EN` 现在驱动 **`MAX98357A` 的 `SD_MODE`**，⚠️ **< 0.16 V = `Shutdown`（没声音）** ⇒ ⭐ **`PULL_MODE=UP` 依然是安全态**（高 = 出声，⛔ 不会误关）。🔴 **但脚和极性都要改**：`AB16` → **`Y14`**，且上电后**必须驱动【高】**。✅ 旧版 `.cst` 的 `PULL_MODE=UP` 保住了"配置期间高"这一半；仿真侧 `tb/top/tb_top_m0.sv` 验的是**旧极性**（拉低）⇒ ⚠️ **该断言要跟着改**。⭐ 详见 `files/10-硬件/板卡替换评估/Console引脚查证-20260922.md` §一<br>⭐ 已核实（2026-09-30 夜）：`constr/top.cst` 早已按换板结论落地 —— `PA_EN_n` 已从 `AB16` 改为 **`Y14`**，且写的是 `IO_TYPE=LVCMOS15`（⭐ `BANK9` = 1.5 V 域）+ `PULL_MODE=UP` ⇒ 配置期间被拉高 = `SD_MODE` 高 = 出声安全态 —— 见 `constr/top.cst:118-119` |
| **K-43** | ⭐ **板级「活体见证」的脚**：🔴 旧 `LEDs[0] = T18`（NEO Dock）→ ⭐ **新 `led_heartbeat = V13`**（`SYS_ACT`，Console） | 🔴 **换板后必须改脚**：⚠️ `T18` 在 Console 上是 **`SDRAM1_D6`**（⛔ 驱动它不会点亮任何用户灯）；⭐ Console 上**唯一**由 FPGA 驱动的用户可见灯是 `CFG_LED` 的**绿路 = `SYS_ACT` = `V13`** （红 = `READY`、蓝 = `DONE` 由配置逻辑驱动，⛔ 我们碰不到）。⚠️ 旧板 `T18` 与 **`SDRAM1_D6` / PMOD** 复用。之所以还要占它：`K-41` 的教训（上一个项目全设计换了 PLL 时钟 ⇒ **板子全死、连 UART 都没输出、综合却零 error**）⇒ ⭐ **必须常驻一个"留在板载时钟域、不依赖任何新时钟/新外设"的活体信号**（本设计 = 顶层心跳 LED + 板载 50 MHz 时钟） | RTL + `constr/top.cst` | 将来若用 SDRAM/PMOD 必须先换脚 | ✅ **已修**（⭐ 2026-09-30 回填；⭐ 原标 **🔴 待改** —— 原文记录保留）：`constr/top.cst` 的 `led_heartbeat` 仍是旧 `T18` ⇒ ⭐ **要改成 `V13`**（⚠️ 集成层 ⇒ 要通知全员）。✅ 本设计**不用 SDRAM、不用 PMOD**<br>⭐ 已核实（2026-09-30 夜）：`constr/top.cst` 早已把 `led_heartbeat` 从旧 `T18` 改到 **`V13`**（⭐ `SYS_ACT`，`IO_TYPE=LVCMOS33`），`.cst` 里已无 `led_heartbeat` 占用 `T18` —— 见 `constr/top.cst:127` |
| **K-44** | ⭐⭐ **延迟预算（M2 实测）**：从 `UP/DOWN` 事件到**板上 DAC 收到数据位**，`max = 1263 clk_sys = 1.233 音频帧`（≪ 2 帧判据） | 50 次实测（`tb/latency/tb_latency_m2.sv`，用**真 `clk_gen` + 真 `i2s_tx`**、合成激励）。⭐ 关键结论是**分解**：其中 **322~1260 clk 是输出级固有**（`i2s_tx` 只在 `frame_start` 装载 ⇒ **帧量化**最多等 1 整帧；+ LSBJ 右对齐要等 16 个空 `BCK` 才发数据位 ⇒ **串行化** 257 clk）。⇒ ⭐ **留给乙的合成链（`note_manager`+`voice`+`mixer`）只剩 785 clk = 15.7 µs**（且必须**最坏情况下**守住） | RTL + 文档 | ⭐ **提高题「≤5 ms 确定性」与基础题观感**；乙的 `voice`/`mixer` 流水线深度 | 🟡 **阶段预算已量化，真端到端复测仍开放**：T10 已用真实 `voice` 完成 M1，但当前 M2 台仍用事件管理桩，且 `note_manager/mixer` 未落地；等 L6 集成后把它们接入同一延迟台复测。若真链超 785 clk，先评估把装载点从“帧起点”移到“左声道数据位开始前”（仅限左右同源且禁止帧内切换），不能靠忽略流水延迟过关 |
| **K-45** | ⭐⭐ **Gowin 构建的两条警告（`TA1132` / `PR1014`）含义不同，⛔ 别混为一谈** | ① `WARN (TA1132) 'clk' was determined to be a clock but was not created` = **没有时序约束文件**（`<Timing Constraints File>: ---`）⇒ **时序分析是空的**，"布线通过+生成 bitstream"说明不了任何时序问题。✅ 补 `constr/top.sdc`（`create_clock -period 20`）后消失。② `WARN (PR1014) Generic routing resource will be used to clock signal 'clk_d'` = **时钟经通用布线进主干**。⭐ 已用工具自己的数据查清成因：包内专用时钟脚的 `CFG` 列是 `GCLKT_n`/`GCLKC_n`，而**板载时钟脚 `V22` 的 `CFG` 是 `EMCCLK`**（不是专用时钟脚）⇒ `GCLK_PIN 0/40`。⚠️ 但 `Global Clock Signals` 显示 `clk_d → PRIMARY`（**上了全局主干**）+ Setup/Hold 违规端点 **0** + `Fmax 332.9 MHz` ⇒ **实际无害、且改不掉**（⛔ 不许为消警告挪时钟脚） | RTL + 工程 | 一切"上板能不能跑"的判断 | ✅ **已查清（2026-09-17）**：详见 ⭐ `files/20-代码/工具链与Gowin工程.md` §三/§七 |
| **K-46** | ⛔ **高云 `.gprj` 里文件 `type` 写错会"静默跳过"该文件**（零警告、照样 exit 0、照样出 bitstream） | 2026-09-17 实测：把 `.sv` 登记成 `type="file.systemverilog"` ⇒ 日志里**既无** `Analyzing … .sv`**也无** `Compiling module`，**文件根本没被读**。✅ 正确写法：`.v` 与 `.sv` **都写 `type="file.verilog"`**（依据：官方例程 `IDE\data\examples\cpu\cpu.gprj`） | 工程/工具链 | ⭐ 一切"我的模块过了工具链"的判断 | ✅ **已查清**：⭐ **每次加文件后必须在日志里确认 `Analyzing …` 那行出现**；⚠️ 附带发现**"被解析" ≠ "被综合"** —— 未被顶层例化的模块**只分析不编译**（实测 `tlc5916_driver.sv` 只有 `Analyzing`）⇒ ⛔ "加进工程且构建通过"**不能**当"它能综合"的证据。详见 `files/20-代码/工具链与Gowin工程.md` §六 |
| **K-47** | ⭐⭐ **`i2s_tx` 与 PT8211 的采样沿关系**（2026-09-17 由**手册原文**发现并修） | 手册（Princeton PT8211 V1.5 §FUNCTION DESCRIPTION）逐字写着：**"Each valid DIN data will be shifted to the input register in the rising edge of the BCK"** ⇒ **DAC 在 BCK 上升沿采 DIN**。⚠️ 我们原来 `HP_BCK` 与 `HP_DIN` 在**同一个时钟沿**更新 ⇒ 对 DAC 而言**建立时间 ≈ 0**。⚠️⚠️ **这个缺陷仿真抓不到**：`tb/models/i2s_rx_model.sv` 是"检测到上升沿后**再打一拍**"才取 DIN ⇒ 对"数据在哪个边沿变化"完全不敏感。⭐ 同一份手册还纠正了两条"想当然"：① **WS 低 = 右声道**（与标准 Philips I2S 相反；本项目单声道 ⇒ 无听感影响，真要分左右用 `LRCK_POL`）② 手册**没有 tSU/tHD**，只有 tH ≥ 25 ns | RTL + tb | ⭐ 上板出声正确性（最典型的"仿真过、上板错"） | ✅ **已修**：`HP_BCK` 复位值 `0→1` ⇒ 数据在**下降沿**变、DAC 上升沿采 ⇒ **建立/保持各 160 ns**（采样点落在数据窗正中）。⭐ 新增 `tb/w3c/tb_i2s_tx_timing.sv` 逐位量 tSU/tHD/WS setup，并把手册的 `Fbck≤18.4MHz / Fws≤384kHz / tH≥25ns` 一起断言（实测裕量 5.9× / 7.9× / 6.4×） |
| **K-48** | ⭐ **`i2s_tx` 参数组合的"静默丢位"** | ① 左对齐（`JUSTIFY=0`）要求 `SLOT_BITS ≥ DATA_BITS + MSB_DELAY`：`SLOT_BITS=16/DATA_BITS=16/MSB_DELAY=1` 时**最低 1 位永远发不出去**（只发 15 位）；② 右对齐要求 `SLOT_BITS ≥ DATA_BITS`，否则取到**低位**（丢 MSB = 噪声）；③ `SAMPLE_W < DATA_BITS` 时 `sh_l[SAMPLE_W-1 -: DATA_BITS]` **低位越界**（仿真 x / 综合零扩展，两边不一致）。三者都**不报错** | RTL | 将来"顺手改个参数"就踩 | ✅ **已修**：`PARAM_OK` 覆盖两种对齐；新增 `top_bits()` 按位取、越界补 0；⭐ 新增 `tb/w3c/tb_i2s_tx_sweep.sv` **7 套配置全档扫档**（含 `SLOT_BITS==DATA_BITS` 时左右对齐**位流逐拍相同**的交叉验证，以及"不自洽参数必须对不上"的负向证明） |
| **K-49** | ⭐ **"被解析"≠"被综合"**（Gowin 只编译**从顶层可达**的模块） | 实测：`tlc5916_driver.sv` 登记正确后日志只有 `Analyzing …`、**没有** `Compiling module 'tlc5916_driver'` ⇒ ⛔ "加进工程且构建通过"**不能**当"它能综合"的证据（这是 `K-46` 的延伸） | 工程/工具链 | 多人协作时"我的模块能不能综合" | ✅ **已解决**：新增 **合成自检顶层** `bringup/synth_check_top.v` + `bringup/synth_check.gprj` + `bringup/synth_check.tcl`（把所有要检查的模块都例化一遍，`run syn`）⇒ 现在能拿到 `Compiling module 'tlc5916_driver'` 与**每模块资源**（`clk_gen` 15FF/11LUT · `i2s_tx` 24FF/18LUT · `tlc5916` 30FF/52LUT） |
| **K-50** | ⭐⭐ **异步输入必须"同步释放"**（R-08）：`rst_n` 来自板上按键，是**异步**输入 | 本设计统一用同步复位，但直接把异步 `rst_n` 分发到所有 FF，会让**释放沿**在不同 FF 上落在不同时钟沿（一部分复位了、一部分没复位），且各模块互相不一致 —— 仿真里复位是理想沿，**永远看不出** | RTL + 顶层 | 上电行为、偶发"某模块没复位" | ✅ **已修**：新增 `rtl/rst_sync.v`（异步输入 → **同步释放**，2 级；代价 = 复位生效晚 2 拍 = 40 ns），`top.v` 内部改用 `rst_n_sync`。⭐ 判据：`tb_top_m0` 实测延迟**恰好 2 拍**。⚠️ 它**不**去抖机械抖动（那是 `debounce`/`T14` 的事） |
| **K-51** | ⭐ **`clk_gen` 的参数必须是 2 的幂**（R-17），否则**静默给错频率** | 该模块把 `$clog2` 当移位量/位选用，只在 2 的幂时等于真除法：`BCLK_DIV=12` 实际仍按 ÷16 走（实测 4096 拍里 258 次 ≈ 256，而非 ÷12 应有的 341） | RTL | 换 `fs`/分频比时 | ✅ **已加自检**：`is_pow2()` + `PARAM_OK` + `initial` 告警；⭐ 负向用例 `tb/clk_gen/tb_clk_gen_badparam.sv` **用数据证明**了"静默错频率"。⚠️ 只是**仿真侧**告警（综合工具忽略 `initial`）⇒ 上板前靠人查，已写进 `files/20-代码/工具链与Gowin工程.md` 的验收清单 |
| **K-52** | ⭐ **`start` 在 busy 期间不能被静默丢弃**（R-09） | 原来只有 `IDLE` 分支看 `start` ⇒ 传输中（≈8.5 µs）来的 `start` 无声消失，现象是"偶尔丢一帧灯"，极难定位 | RTL | LED 刷新 | ✅ **已修**：加 `pending` 位，busy 期间来的 `start` 记住、回 `IDLE` 后**补发一次**（语义 = "至少写一次"） |
| **K-53** | ⭐⭐ **Fmax 必须连同"约束了什么"一起引用**（2026-09-17 实测） | 只写 `create_clock` 时，**进出引脚的路径压根不被分析** ⇒ 报告给 `Actual Fmax = 325.9 MHz`；补上 `set_output_delay`（`constr/top.sdc`）后同一份设计变成 **55.96 MHz**。⭐ **两次都是"0 违规"**，但前者是"没查外部路径所以没违规"。⚠️ 最差路径实测 = `u_i2s_tx/ch_s2 → HP_WS_obuf`（建立裕量 2.130 ns），正是"只算内部路径会漏掉"的那类 | 工程/时序 | ⭐ 一切"时序余量够不够"的结论；32 voice 的资源/时序预算 | ✅ **已修正**：`.sdc` 补了 `set_output_delay`（音频三线）+ `set_false_path`（`PA_EN_n`/`led_heartbeat`/`rst_n`，**每条都写了理由**）；⭐ 真实余量 = **55.96/50 = 1.12×**（达标但不宽裕）⇒ ⛔ **每加一个模块都要重跑** |
| **K-54** | ⭐⭐ **回归脚本的 FAIL 判定正则既要"不漏"又要"不误判"** | 原判据 `(?m)^\s*FAIL`：① `\s` 在多行模式下**含换行** ⇒ 可能跨行匹配；② 要求 `FAIL` 前**只有空白** ⇒ 若 tb 打印 `"  ⛔ FAIL: …"` 会**静默漏判**（该失败却报通过）。⚠️ 但**放宽成"行内含 FAIL 即失败"也不行**：实测 `tb_i2s_tx_sweep` 会打印说明性文字 `<- MUST FAIL`（讲"这一档本应失败"）⇒ 被误判成失败（**假失败**，tb 其实 PASS） | 回归脚本 | ⭐ **所有验收结论**（脚本漏判 = 全部结论失效） | ✅ **已修**：判据定为 `(?m)^[ \t]*[^A-Za-z]*FAIL:`（行首允许空白 + **非字母**装饰符；字母开头的 `MUST FAIL` 不算）。⭐ 并**端到端验证**：临时造一个故意失败的 tb ⇒ 正确判失败 + `exit 1`（验证后已删）。⚠️ 纪律写进 `仿真与验证方案.md` §六：**结论必须用 `FAIL:`（带冒号）**；讲"本应失败"请写 `MUST FAIL` |
| **K-55** | ⚠️ **编辑 `sim/*.ps1` 后必须复查 BOM** | 2026-09-17 实测：编辑工具**会剥掉 UTF-8 BOM** ⇒ 无 BOM 的 `.ps1` 在 PS 5.1 下按 **GBK** 解码 ⇒ 中文注释变乱码 ⇒ **语法报错**（现象是"我明明只改了正则，脚本却跑不起来"）。⚠️ 这条与 `K-38`/`U46` 是同一个坑，但**触发点不同**：这次不是"新建脚本忘了加 BOM"，而是**编辑既有脚本时被静默剥掉** | 工具链 | ⭐ 一切 `.ps1`（回归入口） | ✅ **已确认并处理**：本轮两次改 `tb_all.ps1` 都被剥掉 BOM，两次都靠"**复查前 3 字节 = 239,187,191**"发现并补回。⭐ 纪律：**每次编辑 `sim/*.ps1` 后都要复查 BOM**（写进 `K-38` 的配套） |
| **K-56** | ⭐⭐⭐ **"全绿"不等于"验过了" —— 必须证明判据会失败（变异测试）** | 本项目验收**全部依赖仿真**（没有系统板）⇒ "判据的有效性"是最底层前提。⛔ "所有 tb 都 PASS"本身不能证明任何事：**若判据根本不会失败，"全绿"和"没测"没有区别**（本项目已多次踩到判据缺陷：阈值笔误恒 FAIL、覆盖缺口、"8/8"其实只测 4 个、模型结构性不敏感…） | 验证方法论 | ⭐ **所有验收结论的可信度** | ✅ **已建立**：`bringup/mutation_test.ps1` —— 每次只改**一处已知缺陷**（改真实 RTL），要求整条回归**必须变红**；跑完**自动还原 + 逐字节核对**。⭐ **当前 17/17 变异体全部被抓** —— 8 个改 **RTL**（覆盖 R-03/K-01/K-03/K-42/R-08 等历史缺陷的回归）+ 4 个改**判据自身**（A1/A2/A4A5 检查器 + S2 模型）⇒ 证明"每一条已修缺陷都有一条真能抓它的判据"。⛔ 将来某个变异体变 GREEN = **那条判据被改坏了** |
| **K-57** | ✅ **`OE` 稳定窗已提到满足手册 `tw(OE) ≥ 500 ns`**（2026-09-17 查本地 TLC5916 原件发现并修复） | 本地 `tlc5916.pdf`（TI 原件）时序表原文：`tw(OE) Pulse duration, OE(ED2) **500 ns**`（另有 `tw(ED2) ≥ 2 µs` 是 Error Detection 模式的要求）。原来 `OE_STABLE=8` 拍 @50 MHz = **160 ns** ⇒ **短于 500 ns**。⚠️ 它**不约束正常使用**（我们从不有意进 Special Mode），风险在**反面**：误产生"短于 500 ns 的 OE 低脉冲"会落在"既不被识别为有效脉冲、又恰好跨过某个 CLK 沿"的模糊区 | RTL | LED 驱动集成（`T5`） | ✅ **已修**：`OE_STABLE` **8 → 25 拍（500 ns）** + 加**参数自检**（`TLC_PARAM_OK`/`OE_NS`，换时钟时 <500 ns 会告警）。⚠️⚠️ **修的过程踩到真坑**：自检第一版 `OE_STABLE*1e9/CLK_HZ` **32 位有符号溢出** ⇒ 算出 **−15 ns**、自检**反而误报** ⇒ 改用 **`longint`**（"溢出"和"算错"长得一样）。⭐ 并加**硬断言**（`tb_tlc5916_driver`）+ 变异体 **M14**（改回 8 拍）**已被抓到** —— ⚠️ 一开始只打 `ERROR` 而回归**只认 `FAIL:`**，是变异测试把这个缺口逼出来的 |
| **K-58** | ✅ **PT8211 手册原件已补全（V1.7）** | 原来只有 **4 页**（页脚 `V1.6 2`→`3`→**`8`**，缺第 4~7 页 = 时序章节），`K-47` 的"BCK 上升沿采样"与"WS 低=右"依据的是**网络 V1.5 镜像**。⭐ **现已补全为 V1.7（2022-08，7 页）** | 参考资料 | ⭐ `R-03`（最严重那条 🔴）的**依据强度** | ✅ **已关闭**：V1.7 原文逐字确认 **①"…shifted to the input register in the rising edge of the BCK"** ②**"WS Low → right; High → left"** ③**"LSBJ" + "2's complementary" + "MSB first"** ④**"only the first 16bit data (from MSB) is valid if the input data length is more than 16bits"** ⇒ `JUSTIFY=1` 与"高 16 位有效"**全部是手册预期**。⚠️ 新记：手册**自相矛盾**（正文说 BCK ≤20 MHz、时序表说 ≤18.4 MHz）⇒ 取保守 18.4 MHz；`tR/tF ≤ 20 ns`；`VIH ≥ 1.8 V`（⚠️ 若误配 `LVCMOS15` 会不足） |
| **K-59** | ✅ **MCP3208 SPI 时序限值已抄录并算好分频**（2026-09-17） | 之前仓库里**只有型号与通道数、没有时序限值** ⇒ 丙写 `T11` 驱动要临时翻手册。现已抄录：`f_CLK ≤ 2.0 MHz`(5V)/`1.0 MHz`(2.7V)、`t_HI/t_LO ≥ 250 ns`、**`t_SUCS ≥ 100 ns`**（CS 拉低后等 ≥100 ns 再发时钟，**最容易漏**）、`t_SU ≥ 50 ns`、`t_CSH ≥ 500 ns`、`t_CONV = 12 clk`、⚠️ 脚注 3"**有效时钟低于 10 kHz 影响线性度**" | 参考资料 | `T11`（ADC 驱动，丙） | ✅ **已完成**：⭐ 顺手算好分频 —— `clk_sys ÷ 50 = 1 MHz`（**整数分频**；2 MHz 需 12.5 拍**不是整数**）；24 通道轮询一遍 **372 µs ⇒ 每通道 2.69 kHz**（方案里的 2 kHz 目标**满足**）。详见 `files/40-参考资料/芯片手册核对记录.md` §四 |
| **K-60** | ⭐ **三片 `MCP3208` 的 SPI 引脚共享口径（本次查手册后有修正）** | 手册 §3.7 原文：*"The `CS/SHDN` pin is used to initiate communication … when pulled low and will end a conversion and put the device in **low power standby** when pulled high. **The `CS/SHDN` pin must be pulled high between conversions.**"* ⇒ **`CS` 必须独立**（共用会同时启动三片 ⇒ `DOUT` 总线争用）。⚠️ 而 `MISO`：手册 §5 + 时序表 `t_DIS ≤ 100 ns` 表明 **`CS` 高时 `DOUT` 确实进高阻** ⇒ ⭐ **电气上可共享**，`K-06` 原来写的"**必须**独立（没有高阻证据）"**依据不准** | 硬件 + RTL | ADC 采集链接口 | ✅ **口径已修正**：结论**不变（仍然 3 路独立）**，但**理由改为工程性** —— ① 引脚够用（`J13`+`J14`=80 脚，只需 30~45）② 三态切换有 100 ns 窗口，共享时若两片 `CS` 同时低会**推挽对打**（独立最多读错数据、不电气冲突）③ 可诊断性 ④ `A5` 检查器（`MISO` 单驱动）因此**有意义**。⭐ 详见 `files/10-硬件/拓展板连接方案.md` §二 |
| **K-61** | 🔴🔴 **`NS4263` 功放的 `SD` 脚不是普通使能 —— 它靠"下降沿个数"选模式**（2026-09-17 查手册原件发现） | 本地 `NS4263` 手册 §10.1 模式表原文：**"初始化低 或 一个下降沿 = AB 类桥式输出"**；**"连续两个下降沿 = D 类桥式输出"**；"低 + `HP-IN` 高 = AB 类单端（耳机）"；**"高（>100 µs）= 低功耗关断"**。⚠️ 电气特性表还给了 `THI SD 高电平时间 1~12 µs` / `TLO SD 低电平时间 1~12 µs` ⇒ **高低电平的持续时间也在被计数** —— 与 `TLC5916` 的 Special Mode 是**同类陷阱** | RTL + 硬件 | ⭐ **音色/EMI 正确性**（我们以为在 AB 类，可能实际在 D 类） | ✅ **已修**：`rtl/top.v` 的功放使能改成**"只允许上电后恰好 1 个下降沿"** —— 加 `pa_done` 锁死位，开功放后**永不再变**（⛔ 不加"关断"分支，那会产生第 2 个下降沿 ⇒ D 类）。⭐ `pa_cnt` 位宽改用 `$clog2`（顺手修掉 `R-16`：原来 24 位，`PA_ON_DELAY>16.7M` 永不到）。⭐ `tb_top_m0` 加**断言 H**（统计下降沿个数：安全态 0 个、延时开功放**恰好 1 个**）+ 变异体 **M15** 守着 |
| **K-62** | ⭐⭐ **异步输入必须同步；上拉解决的是另一个问题**（2026-09-17 用户提问引出） | 用户问"FPGA 上拉比较慢，要不要防亚稳态"。⭐ **要把三件事分开**：① **电平不确定**（悬空）⇒ 靠**上拉**；② **时刻不确定（亚稳态）** ⇒ 靠**同步器（2 级 FF）**，⛔ **上拉完全解决不了**；③ **机械抖动** ⇒ 靠**去抖计数器**。⚠️ FPGA 内部上拉是**弱上拉**（10~50 kΩ 级）⇒ 对 ~10 pF 线 `τ=RC≈100 ns`、到 90% ≈230 ns，**与 1 MHz SPI 的 500 ns 半周期同量级** ⇒ ⭐ **`MISO` 不要靠上拉拉高**（高电平应由从机推挽提供），但 ⭐ **按键抖动是 ms 级**、比上拉慢 4 个数量级 ⇒ **上拉慢完全不影响按键** | RTL + 硬件 | ADC 采集链、按键 | ✅ **已处理**：新增 **`rtl/sync_input.v`**（2 级 FF、可参数化位宽、逐位同步）。⭐ 口径写进 `files/10-硬件/拓展板连接方案.md` §4.2b。⚠️ **仍待做**：把 SPI/按键输入**实际接上** `sync_input`（等 `T11`/`T14`）；⭐ 并建议 **`.cst` 给所有输入脚写 `PULL_MODE=UP`**（不依赖板上电阻 ⇒ 左右板行为一致） |
| **K-63** | 🔴 **`longint` / `longint'()` 在 Gowin 里不可用 —— "仿真过 ≠ 综合过"**（2026-09-17 实测） | 修 `K-57` 的参数自检时，为避免 32 位溢出用了 `localparam longint` + `longint'(...)`：**iverilog 通过**，但 **Gowin 报 `EX3863` 语法错 + `EX3872` 未声明**，整个 `tlc5916_driver` 被忽略。⭐ 改用**先除后乘**（`PER_CLK_NS = 1e6/(CLK_HZ/1e3)`，即 `1e9/CLK`）⇒ **两边都支持且不溢出**。⚠️ 附带教训：改这个算式时我又把中间量误当"千分之一 ns"、多除一个 1000 ⇒ 算出 **0 ns**、自检误报 —— 📌 **"单位"必须靠量纲推导确认，不能靠感觉** | 工具链 | ⭐ 一切"仿真过就以为没事"的写法 | ✅ **已修**：`rtl/drivers/tlc5916_driver.sv` 用 `PER_CLK_NS` 先除后乘；**仿真 500 ns 正确 + Gowin exit 0**。⭐ 纪律：**每加/改一个模块都要重跑 `sim/gowin_build.ps1`**（这正是它的存在理由）；⛔ 不要用 `longint`/`real`/`$rtoi` 等非 Verilog-2001 子集写**可综合**代码 |
| **K-64** | ⚠️ **左手板 `LE` 的 10K 上拉与 TLC5916 内部下拉方向相反**（2026-09-17 从**实际网表**发现） | 实际网表 `lefthand_board.tel`：`R12` = **10K 上拉到 `3V3`**，接在 `LE` 上。而手册原文：**"`LE(ED1)` has an internal pulldown."** ⇒ **方向相反**。外部 10 kΩ 远小于内部下拉（同类通常 100 kΩ~1M）⇒ **FPGA 未配置期间 `LE` ≈ 高**。⚠️ 上电瞬间 `LE` 为高会让**移位寄存器内容被锁存到输出**，而上电时其内容**不确定** ⇒ **可能闪一次随机灯**。✅ 不构成 Special Mode 前提（`OE` 有 10K 上拉 ⇒ 悬空为高 = 关断）；✅ FPGA 驱动后推挽完全压过 10 kΩ ⇒ 正常工作不受影响 | 硬件 | 上电瞬间的观感（可能闪灯） | ⚠️ **已记录，待上板确认**：上电看有没有闪灯。⭐ 若要彻底消除：把 `R12` 改**下拉**或**去掉**（手册本来内置下拉）。⛔ 不必改 RTL（RTL 侧的 `LE` 纪律已由 `K-03` 的 `STATE_LE_WAIT` 保证） |
| **K-65** | ⚠️ **实际 PCB 与文档口径有 3 处不一致**（2026-09-17 从网表核对发现） | ① 左手板 `SPI_1` 是 **8 针 `XH2.54`**（`CS/GND/MOSI/GND/MISO/GND/MCP_CLK/GND`），⛔ **不是文档写的 7 针含 `3V3`**；② 信号名是 **`MCP_CLK`**（经 33 Ω 串阻），不是 `SPI_SCLK`；③ LED 座 `LED_1` 也是 **8 针**（`LE/GND/LED_CLK/GND/SDI/GND/OE/GND`）。⚠️ 两个 8P 座**外形相同、针位定义不同** ⇒ 插错会不工作/损坏 | 文档 + 硬件 | 接线、写驱动时的信号命名 | ✅ **已核对并记录**：新增 **`files/10-硬件/已画PCB网表核对.md`**（逐条"文档↔网表"比对，**以网表为准**）。⭐ 好消息：实际排线**已做到"一信号一 GND"** ⇒ 印证"30 cm 不需要屏蔽线"；⭐ 且**所有 SPI/LED 信号都有 33 Ω 源端串阻**（抑制振铃，好事）；⭐ `AGND`—`GND` 用 **0 Ω 单点汇合**（与画板注意事项一致）。⚠️ 待办：把接口总表的 `J3` 定义改成 8 针实际口径 |
| **K-66** | ⭐⭐ **TLC5916 上电 Normal-Mode 恢复序列已实装**（2026-09-17，把"进了 Special Mode 只能断电"降级为"开机自愈"） | 手册 Figure 16 + NOTE 原文：**"once a one-clock-wide short pulse (101) of OE(ED2) appears … At the fourth rising edge of CLK, if LE(ED1) is sampled as voltage high, TLC591x switches to Special Mode; otherwise, it switches to Normal Mode."** ⭐ 且 **NOTE 1 明确背书**："The signal sequence for the mode switching **may be used frequently to ensure that TLC591x is in the proper mode**." ⭐ **NOTE 3**："After power on, the default operation mode is **Normal Mode**." | RTL | ⭐ 现场演示稳定性（把最难诊断的故障变成可自愈） | ✅ **已实装**：复位释放后**一次性**发 `REC_PERIODS=6` 个 `tlc_clk` 周期，`LE` **全程低**、`OE` 拉低**恰好 1 个完整 CLK 周期**（`= 1000 ns ≥ tw(OE) 500 ns`）且**恰好跨过 1 个 CLK 上升沿** ⇒ 第 4 个沿采到 `LE=低` ⇒ **强制回 Normal Mode**。⚠️ 这段**故意**违反防护②（"OE 只在 CLK 静止时变"），安全性由三点保证：① 只在复位后跑一次；② `LE` 全程低 ⇒ **只能切到 Normal**；③ 脉冲宽度达标。⭐ 恢复期间来的 `start` 用 `pending` 记住**不丢**。⭐ **`tb_tlc5916_driver` 新增 5 条 K-66 判据**（跨过的上升沿数 = 每窗口 1 个、`LE` 全程低、宽度 ≥500 ns、CLK 周期数 ≥5、每次复位恰好跑一次）+ 变异体 **M16/M17** 守着。<br>⚠️⚠️ **实现过程中踩了 4 个坑（都值得记）**：<br>① **第一版把 `OE` 下降沿与 CLK 上升沿对齐** ⇒ 有 setup/hold 歧义 ⇒ 改为"低窗口**居中**跨过上升沿"；<br>② **用"周期内相位"判断低窗口** ⇒ 窗口被截断在周期末尾（实测只有 **260 ns** 且**跨不过任何上升沿**）⇒ ⭐ **跨周期边界的窗口必须用绝对相位**；<br>③ 恢复结束时**把 `OE` 写死为 1** ⇒ 上层要亮时 `tlc_oe_n` 停在错误高电平 ⇒ 改为**重置 `oe_hold`/稳定窗**让主 FSM 接管；<br>④ ⚠️ **tb 里无上限的 `wait (done)` 让整个回归挂死 600 s**（我的 RTL bug 触发了它）⇒ ⭐ **已把所有等待改成有上限**（超时报 `FAIL:` 而不是挂死）—— 这是 tb 自身的真缺陷 |
| **K-67** | ⚠️ **变异体必须真的"违反规格"，否则 LEAK 是假警报**（2026-09-17 实测两次） | 给 `K-66` 加变异体时：① 第一次改 `pa_done` 锁存位 ⇒ LEAK，但**它并没有真的产生第 2 个下降沿**（`pa_en_n_r` 仍保持 0）；② 第一次把 `OE` 窗口缩到 `HALF_DIV`（**恰好 500 ns**）⇒ LEAK，但那**恰好满足**手册 `≥500 ns` ⇒ 判据**正确地**通过了。⇒ ⭐ **两次 LEAK 都不是"判据有盲区"，而是"变异体没造出违规"** | 验证方法论 | ⭐ 变异测试的可信度（`C21`） | ✅ **已修正**：两个变异体都改成**真的违规**（`pa_en_n_r` 真被拉低、窗口缩到 **250 ns**）⇒ 现在**都被抓到**。📌 纪律：**看到 LEAK 先问"这个变异体真的违反规格了吗"**，⛔ 不要立刻去加断言（否则会加出"为变异体量身定做"的假判据） |
| **K-68** | ⭐ **"要不要换更快的时钟源？" —— 结论：不用，收益近零且有风险**（2026-09-17 查实） | 起因：Dock 原理图 `/SYS_CLOCK/` 页有 `100MHz`/`210MHz`/`125MHz` 标签 ⇒ 怀疑"是不是有更快的源、换了会更好"。⭐ **先查实 `V22` 频率**（原来仓库只是断言、没标出处）：三处官方原件一致 —— ① `TMDS_60HZ.sdc` 写 `create_clock -period 20`（= **50 MHz**）；② `NEO_DOCK.cst` 写 `clk = V22`（与我们的 `.cst` **逐字一致**）；③ 两份**独立**例程的 PLL 都写 `FCLKIN = "50"`。⭐ **且 ① 能自证**：同一 `.sdc` 把 TMDS 时钟定义为 `divide_by 200 × multiply_by 297` ⇒ `50×297/200 = 74.25 MHz`（**标准 720p TMDS 时钟**）；若输入真是 100 MHz 会算出 148.5 MHz、**DVI 例程点不亮** ⇒ **反证 `V22` 必是 50 MHz**。板上那些高速网络（`MS5351M` 是**给 SerDes 的 RefClk**、`125MHz` 振荡器、`AB12 USR_CLK_IN` 还在 `BANK9` 必须 `1V5`）**都不是给用户逻辑用的** | 设计决策 | ⭐ 时基选择 | ✅ **结论：继续用 50 MHz，不改**（我们的 `.sdc` 与官方逐字一致）。**逐项量化**：<br>· **`fs`（采样率）**：由**分频比**决定（`clk_sys/1024`），⛔ **不由时钟快慢决定** —— 想要别的 `fs` 改 `CLK_PER_SAMPLE` 即可；48.828 kHz 已最接近标准 48 kHz ✅<br>· **复音数/振荡器数**：由**逻辑资源**决定（59904 FF/LUT 够放 64 lane），⛔ 与时钟无关；每采样有 **1024 clk**，TDM 预算极充裕<br>· **音高精度**：由**相位累加器位宽**决定（32 bit ⇒ A0 误差 0.73 cents），⛔ 与时钟无关<br>· **延迟**：⚠️ 只有这一项与时钟有关，但**代码里流水级数不变** ⇒ **"多少帧"完全一样**（实测 max **1.233 帧 = 25 µs**，仅为 5 ms 指标的 **0.5%**）⇒ 快时钟只让"µs 数"变小，**帧数与听感不变**<br>· ⚠️ **时序收敛**：实测 `Fmax`（含 I/O 约束）= **55.96 MHz** ⇒ 50 MHz 已用掉 **89%** 可达频率！换 100 MHz 要么收不了、要么被迫深流水（**反而增延迟 + 增寄存器**）<br>· 💡 一般做法：**够用就取最低时钟**（省功耗、好收敛）；高速晶振通常只为**高速接口**（DDR3/PCIe/以太网/HDMI）而用 —— 那是"**接口要求固定频率**"，不是"想更快" |
| **K-69** | ✅ **`PA_ON_AFTER_RESET` 默认值改对（`R-16` 关闭）+ 加"交付默认值守卫"**（2026-09-17） | ⚠️ 原默认值是 **0** ⇒ 板载 `NS4263` **永远关断** ⇒ **喇叭/耳机都没声音**，而 I2S 波形、DAC 输入、**所有仿真结论全是对的** ⇒ 这种"没声音"**极难定位**（会让人去查 RTL 白费几小时）。⭐ 根因：把**测试配置**（M0 安全态）当成了**交付默认值** | RTL + tb | ⭐ 上板能不能出声 | ✅ **已修**：① `top.v` 默认值 **0 → 1**（复位后延时开功放，"恰好 1 个下降沿"进 AB 类）；`0` 保留为 **M0 安全态验证档**，由 `tb_top_m0` **显式传 0** 来验。② 加**参数自检**（`initial` 打印档位与延时 ms；⚠️ 不报错，因 `0` 是合法测试档）。③ ⭐ `tb_top_m0` 加**判据 I（交付默认值守卫）**：**裸例化**时必须 = 1；同时反向确认"显式传 0 时确实永不开"。④ 变异体 **M18**（改回 0）**已被抓到**。<br>⚠️ **实现坑**：守卫第一版想"等裸例化实例真的拉低功放"来判 —— 但裸例化的 `PA_ON_DELAY` 是 **1_048_576 拍（≈21 ms）**，而 tb 只跑 64 帧（≈1.3 ms）⇒ **延时根本没到** ⇒ 假失败。⭐ 修法：**直接层次化引用参数值**（`u_top_default.PA_ON_AFTER_RESET`）—— 那才是"默认值守卫"该查的东西 |
| **K-70** | ⭐⭐ **`A7` 的 `jump_ok` 必须覆盖"静音期"，否则假失败**（2026-09-17，`tb/voice/tb_voice_accept.sv` = 给乙的验收判据包） | 新写的 `tb_voice_accept` 里 A7 报 **15 次违规**。⭐ **探针逐帧打 `d_acc/inc/err` 三列**定位：违规**从松音之后开始**、`d_acc = 0` —— 即 **`note_off` 后 `active=0` ⇒ `acc` 整段停住 ⇒ 之后每帧增量都是 0**。⛔ **那不是缺陷**（没在发声时相位本来就该不动），是**检查器语义与"静音期"这个正常状态之间的矛盾** | 验证方法 | ⭐ 乙的模块落地后能否一次验过 | ✅ **已解决**：`jump_ok` 改为覆盖 **"起振 + 停振 + 整个静音期"**（`note_on \| note_off \| ~voice_active`）。⭐ **关键纪律**：`voice_active` **只放行静音期**，⛔ **变调不放行** —— 那正是 A7 要抓的核心场景。⭐ **并证明过判据会失败**：临时给桩注入"变调时清零 `acc`" ⇒ **16 次违规被抓**。<br>⚠️ **另踩两个坑**：① tb 自造时基写成**组合** `tick_audio`，而真 `clk_gen` 是**寄存**输出 ⇒ **相位差一拍** ⇒ A7 读到增量 0（假失败）⇒ 修成与 `clk_gen` 逐字一致的寄存写法；② `jump_ok` **多打了一拍** ⇒ 与检查器内部 `tick_d`/`jump_ok_d` **同拍锁存**的约定错开 ⇒ 漏放行。⭐ 教训：**gate/放行类端口必须与它触发的事件同拍**，并看清检查器是"同拍判定"还是"打一拍判定" |
| **K-71** | ⭐⭐ **"换板只换外壳与引脚表"落成工程 + 三个实测坑**（2026-09-17，基石板上板工程） | 目标：用**手上已有的基石板**先验最底层三件事（时钟/复位/I2S），⛔ 不等 Dock。⭐ **做法**：新建**独立工程** `bringup/jishi/`，用**相对路径**引用**同一份** `rtl/` 逻辑 ⇒ **只维护"外壳 + 引脚表"两份东西**（这正是"逻辑可移植、引脚不可移植"的落实）。⚠️ 三个实测坑：<br>① **ball 不能照抄官方例程** ⇒ `CT1113`（Can't find pad location；官方例程面向**封装变体不同**）<br>② ⭐⭐ **"能解析" ≠ "能用"**：`PR2017`（能解析但落不下去：专用脚 CPU/MSPI，与 `R19` 同类）、`PR2028`（约束在当前封装无意义）—— 我第一版探测器**只查 `CT1113`**，把 `L12` 判成 legal，正式跑时才在**布局阶段**报错<br>③ ⚠️ **报告文件名是 `jishi.*` 而不是 `jishi_top.*`**（输出基名取**工程名**）⇒ 抄证据的路径写错只报 `not found`、**退出码仍 0** ⇒ 容易误判成"报告没问题" | 工程/上板 | ⭐ 上板第一天的效率 | ✅ **已解决**：① 新增 **`probe_balls.ps1`**（⭐ ball 合法性探测器：**把 `CT1113`/`PR2017`/`PR2028` 三种报错都判 ILLEGAL**）⇒ 实测筛出 `K13/L14/L16/M15/P16/T16/V18/V19` 可用；<br>② 报告路径**先列 `impl/` 实际产物再写**；<br>③ ⭐ **一条龙已跑通**：退出码 0、ERROR 0、**违规端点 0/0**、`Actual Fmax 55.258 MHz`、**7 脚全落位**（含 `beep` 的 `PULL_MODE=DOWN`）⇒ 详细指南见 `bringup/04-基石板上板验证指南.md` |
| **K-72** | ⭐⭐ **"从任何地方都能跑"的脚本，不能含依赖调用方当前目录的路径**（2026-09-17 实测） | 现象：用户在 `C:\Users\hokuu`（**不是仓库根**）跑<br>`powershell -File bringup\jishi\build_jishi.ps1` ⇒ 报**「实际参数不存在」**。⚠️ 根因是 `-File` 的路径**按用户当前目录**解析，⛔ 不是按脚本位置。⭐ **修的过程中还发现第二个同类问题**：脚本内部把**相对路径**传给 `gw_sh`，于是"从别的目录跑"会在 **Tcl 侧**找不到工程 —— ⚠️⚠️ **失败现象像"工具坏了"**（报 `while executing "open_project bringup/..."`），**不像路径问题** | 脚本/工具链 | ⭐ 所有"一条龙"脚本的可用性 | ✅ **已修**：① `build_jishi.ps1` 的**一切路径**由 `$PSScriptRoot` 推出；② **动态生成**一个小 Tcl（把工程**绝对路径**写进去）⇒ ⛔ **不把绝对路径提交进仓库**（否则换机器就废）；③ PASS/FAIL 提示也改成打印**绝对路径**（原来打印相对路径，从别处看会误导）。⭐ **实测：从仓库根与从 `C:\Users\hokuu` 跑，结果一致（都 PASS）**。📌 教训：**判据/提示里也别用相对路径** —— 那会让"能跑但提示指向不存在的路径"，把自己绕进去（同 `C19` 家族） |
| **K-73** | ⭐⭐ **选 IO 要满足两个条件：「能落位」+「引到了够得着的地方」**（2026-09-17 实测） | 给基石板上板工程选 I2S 三线的 ball 时，我按"**能落位**"标准探测（筛掉 `CT1113`/`PR2017`/`PR2028`），选了 `K13`/`L14`/`L16`，工程**跑通、0 违规**。⚠️ 但**抽文核对扩展板原理图后发现：这三个脚根本没引到板上任何排针/焊盘** ⇒ **示波器量不到** ⇒ 所谓"验证"根本没法做。⇒ ⭐ **修法**：改用 **`J14.19/20/21`**（`T18`/`F20`/`R17`）—— `J14` 是 **ADA107 的 2×15 排针**，脚位 19~30 是 DAC 那半边，本项目用不到 ⇒ **杜邦线直插即可量** | 工程/上板 | ⭐ "选了一堆脚却发现量不到"这种白干 | ✅ **已解决**：`bringup/jishi/jishi.cst` 已改到 `J14.19/20/21` 并**重跑一条龙**（exit 0 / 0 违规）。⭐ **判据补进指南**：选脚 = ①**能落位**（工具探测）**且** ②**引到排针/焊盘/测试点**（查原理图）。📌 **教训：工具只能告诉你"能不能落位"，"够不够得着"必须查板级资料** —— 两件事都不是另一个的推论 |
| **K-74** | ⭐ **测数字信号不需要 SMA/BNC**（2026-09-17 澄清） | 疑问："方便改成 SMA 吗？" —— ⭐ **先分清两件事**：**I2S 用哪个 ball** 归 `.cst`（一行）；**信号怎么引到示波器** 归**物理层**（杜邦线/排针/SMA 座）。⭐ **SMA 只是"最后一厘米"的接头形式** —— FPGA 到排针之间那段是**数字信号**（3.3 V、**3.125 MHz**），**杜邦线/排针/SMA 在电学上没有区别**。SMA 的价值在**高频/长距离/阻抗匹配**；这里信号只有 3.125 MHz、飞线 ≤10 cm ⇒ ⚠️ 焊 SMA 反而多三样麻烦（要焊座、要配 SMA 转 BNC 线、要考虑阻抗不连续），**收益为零**。📌 且**这块基石板上没有 SMA/BNC 座**（抽文核对：`SMBJ12CA` 是 TVS 二极管、不是座子） | 仪器/测量 | ⭐ 别为"看起来专业"付无谓成本 | ✅ **结论：不改、不用 SMA** —— 杜邦线直插 `J14` 排针即可。⭐ **判据**：信号 > 50 MHz、线长 > 30 cm、或需要 50 Ω 匹配时才值得上 SMA（如以后测 DDR3/HDMI/SerDes）。⛔ 本阶梯信号不属于这类。⭐ **示波器设置也一并写进指南**（DC 耦合 / ×10 探头且软件同选 / 弹簧地线 / 触发源与电平）—— ⚠️ 这些都是"接错了后面全白测"的地方 |
| **K-75** | ⭐⭐ **`HP_DIN` 量到 97.66 kHz 不是故障 —— 判据必须按"最小重复单元"算**（2026-09-18 基石板实测） | 现场：示波器频率计在 `HP_DIN`（`J14.21`）上读 **97.6594 kHz**，而指南里写的期望值是"**≈1526 Hz 方波**" ⇒ ⚠️ 差 **64 倍**，**看起来就是"数据线坏了"**。⬅ 根因：**两个数字都对，是我把判据写错了**。⭐ 算清结构：`SLOT_BITS` = **32** 个 `BCK` = 32 × 320 ns = **10.24 µs**；而**左右声道送的是同一路数据** ⇒ 整帧（20.48 µs）就是**两个一模一样的时隙** ⇒ ⭐ **波形的最小重复周期 = 一个时隙 = 10.24 µs ⇒ 97.656 kHz**（`BCK`/32）。1526 Hz（`TONE_HALF=16`，周期 655.36 µs）**只体现在脉冲宽度上**（±1/4 FS ⇒ **320 ns / 640 ns**，每 **≈328 µs** 交替一次）⇒ ⛔ **频率计永远读不出它** | 文档/测量 | ⭐ "把正常波形判成故障"或反过来"把故障判成正常" | ✅ **已修**：① `bringup/04` §2.0d-2 新增"`HP_DIN` 到底该长什么样"（含结构表与 320/640 ns 的来历：`+1/4FS=0x4000` 只有 **1 个 1**，`−1/4FS=0xC000` 有 **2 个 1**，是**符号扩展**、不是 bug）；② §2.1 判据 2.5 与 §五 症状表同步改写；③ 经验库 `L67`。⭐ **通用规矩**：量**串行数据/分频/帧结构**这类信号，先算**最小重复单元**再定判据；⛔ 别拿"设计里那个音频/事件频率"直接对示波器读数 |
| **K-76** | ⭐ **示波器触发源不用接 `EXT TRIG`（内部选通道即可）**（2026-09-18 澄清） | 提问："触发源是接示波器 `EXT TRIG` 吗？" —— ⛔ **不用**。触发源是示波器**内部**从**已接好的通道**里选一路（`Trigger Source = CH1/CH2/…`）⇒ ⭐ **该路探头接好 = 触发源就接好了**。`EXT TRIG` 那个 BNC 只给两种情况：① 信号**多于通道数** ② 要拿**外部时钟**当基准 —— 本阶梯**两样都不占**。⭐ 双通道机的正解：量 `BCK`/`WS` 时 `CH1=BCK`（触发源、上升沿）；⭐ 量 `DIN` 时用 `CH1=WS`（触发源、**下降沿 = 帧起点**）× `CH2=DIN` ⇒ 脉冲在屏上的**位置**才有意义 | 仪器/测量 | ⭐ "屏上乱/抖/抓不住 ⇒ 以为信号坏" | ✅ **已写进指南** `bringup/04` §2.0c-2（含"乱/抖"的两个真因：**触发源选到没接的那一路** ⇒ 退化成 AUTO 自由跑；**触发电平跑到信号范围外** ⇒ 3.3 V 逻辑取 **1.5 V**） |
| **K-77** | ⭐⭐ **变异测试会把"变异的证据日志"留在 `sim/evidence/` 里**（2026-09-18 发现并修） | 现象：跑完 `bringup/mutation_test.ps1` 后 `git status` 显示 `sim/evidence/*.log` 被改动，⚠️ 而且**改动内容里含 `FAIL:` 行**（如 `FAIL: I · 交付默认值会让板子没声音`）。⬅ 根因：`sim/tb_all.ps1` **每次运行都会重写** `sim/evidence/*.log`；变异测试只在**最后**还原 RTL（**逐字节核对过**），⛔ **但没管它跑出来的日志** ⇒ **最后那个变异体的日志留在了证据目录里**。⚠️ 危险：这些日志**是入库的验收证据**，看起来就像"真的失败了" ⇒ 会让人误判项目状态，也可能被当成"已修缺陷又复发"。⭐ **修法**：`mutation_test.ps1` 结尾**在还原 RTL 之后再跑一次干净回归**（`regenerate sim/evidence from the restored (clean) RTL`），失败则 `exit 3`。⇒ 现在**最后一步永远是干净运行**，证据目录不再被污染 | 验证方法论 | ⭐ 证据目录的可信度（"入库的证据"必须来自干净代码） | ✅ **已修**：`bringup/mutation_test.ps1` 新增第 6 步 + 顶部 NOTE；实测"18/18 全被抓"后**自动重生成干净证据**（`sim/evidence/*.log` 无 `FAIL` 行）。📌 **纪律：任何"会改文件再还原"的测试工具，都要问一句"它跑出来的产物谁来清"** —— 只还原被测文件是不够的 |
| **K-78** | 🔴 **`拓展板连接方案.md` 把 MCP3208 一笔事务算成 "15 个 SCLK" —— 实际最少 19 个，读不出 12 位**（2026-09-19 复核丙的驱动时发现） | 我方文档 `files/10-硬件/拓展板连接方案.md` §三 写："**一帧时长 = 15 个 SCLK（12 数据 + 3 控制/填充）÷ 1 MHz + `t_CSH` 500 ns ≈ 15.5 µs**"，并据此推出"**24 通道轮询一遍 = 372 µs ⇒ 2.69 kHz ✅**"。⛔ **这个数错了**：按手册 5.0 节逐拍数 —— `clock1=Start`、`clock2=SGL/DIFF`、`clock3~5=D2/D1/D0`、`clock6=完成采样保持(don't care)`、`clock7=Null bit`、`clock8~19=B11..B0` ⇒ ⭐ **最少 19 个时钟**才能收齐 12 位。⚠️ 连带"2.69 kHz"这个乐观结论**也是错的**。⭐ 丙的驱动用 **24 个**（前 5 个是引导零，手册明确允许 "clock in leading zeros before the start bit"）⇒ **丙是对的，文档是错的** | 文档/硬件 | ⭐ 采集链的**帧预算**与"能不能达 2 kHz" | ✅ **已确认错在哪**（实测：一笔事务 `CS` 低电平 **24020 ns** = 24 × 1 µs + 边沿）⇒ ⚠️ **待改文档**：`拓展板连接方案.md` §三 表格 + "一帧时长/24 通道预算"两行。📌 **教训：手册的"逐拍数"必须真的逐拍数**，⛔ 别用"12 数据 + 3 控制"这种想当然的拆法 |
| **K-79** | ⭐⭐ **"三片 MCP3208 例化三个"不够 —— 并行方案会让 A4/A5 检查器报违规**（2026-09-19 实测） | 问题："只完成一片，后续例化三个就行吗？" ⇒ ⛔ **不行**：<br>① **`mcp3208_scanner` 是"单片、独占、自走"的**（自己按 `CHANNEL_RATE_HZ` 起帧，**没有"让出总线"的接口**）⇒ 三个并排例化会各扫各的、不保证错开；<br>② ⭐ **实测：三片同 `enable` 时自动锁步**（通道号不一致 **0** 拍、`SCLK`/`MOSI` **完全一致** ⇒ **同源扇出可行**），但 ⚠️ **三片 `CS` 会同时有效** ⇒ ⭐ **挂上项目 A4 检查器（`N=3/ACTIVE_LOW=1`，"至多一个 CS 有效"）实测报 14502 次违规**、A5 同样 14502 次。⇒ ⭐ **并行是"设计意图"不是缺陷** ⇒ **必须裁决 A4/A5 口径**（原口径是照"串行轮询"设计的） | RTL/验证 | ⭐ 三片总控（`adc_farm`）的设计与检查器口径 | ✅ **已实测**：① `SCLK`/`MOSI` 可同源扇出（0 不一致）；② 三片自动锁步；③ `sample_valid` 三路同时来（上层要一次收 3 个样本）；④ ⚠️ **A4/A5 需改口径**。⭐ **帧预算**：一笔事务 ≈ **24.5 µs**（24020 + 520）⇒ **串行 24 笔 = 589 µs ⇒ 1698 Hz/通道（⛔ 达不到 2 kHz）**；**并行 8 笔 = 196 µs ⇒ 5094 Hz** ✅ ⇒ ⭐ **必须走并行**。<br>⭐ **落地（2026-09-20，丙）**：新增 `rtl/drivers/adc_farm.sv`（三片并行总控）—— 片 0 的 scanner 当主控、CS/SCLK/MOSI 三路**同源扇出**、三路 MISO 各自经 `sync_input` 2 级同步后用**影子反串行器**锁步取 12 位、一次 `sample_valid` 原子提交 3×8=24 通道样本；帧周期 **0.5 ms（25_000 周期）**。⭐ **A4 口径裁决**：新增 `tb/checkers/chk_fanout_same.sv`（**A4p**，"同源扇出逐拍一致"）替代 A4 在并行采集下的"三 CS 互斥"判据；A4/A5 原检查器保留（仍适用于串行轮询或其它"至多一个"场景）。变异体 **M21/M22**（片 1 CS 反相 / 片 1 数据错接片 2）均被抓。见 `tb/drivers/tb_adc_farm.sv` + `tb/models/mcp3208_model.sv`（S1 从机模型落地）。 |
| **K-80** | ⭐ **A4/A5 原口径"至多一个有效"不适用于三片并行采集**（2026-09-20 落地 adc_farm 时裁决） | 并行采集下三片 `CS` **本就同时有效**（设计意图），`MISO` 是 3 路独立（不存在共享驱动）。⇒ 原 A4（三 CS 互斥）、A5（MISO 单驱动源）挂在 `adc_farm` 上会**必然误报**（K-79 实测 14502 次）。⭐ **裁决**：并行采集的正确性判据改为 **A4p（`chk_fanout_same`，"同源扇出逐拍一致"）**—— 三片 `CS/SCLK/MOSI` 必须逐拍一致（锁步），一旦某路不同即报违规。A4/A5 原检查器**保留不删**（语义本身正确，仍适用于串行轮询或其它互斥场景）。 | 验证 | 并行采集的正确性判据 | ✅ **已裁决并落地**：`tb/checkers/chk_fanout_same.sv`（A4p）已就册 + 在 `tb_checkers.sv` 里补了**一正一反**自检 + 在 `tb_adc_farm.sv` 里挂到真实三片采集上（CS/SCLK/MOSI 三路）。变异体 M21 证明其会失败。 |
| **K-85** | ⭐ **`adc_farm` 的 `N_ADC` 原本写死 3 ⇒ 后续"加板"（5/6 片）需要参数化**（2026-09-20 扩展） | **起因**：后续可能加键/加板（每块左手板 1 片 ADC）⇒ 需要 >3 片。⚠️ 原代码是 `assign adc_cs_n[1] = adc_cs_n[0];` **写死片 1/2**，`miso1_shift`/`miso2_shift` 也是**两个独立寄存器**。⭐ **关键结论：并行帧时间与片数无关** —— 所有片同时扫**同一通道号** ⇒ 帧时间恒为 `8 笔 × 24.5 µs ≈ 196 µs` ⇒ 5 片/6 片**仍是 5094 Hz/通道** ✅。引脚代价 = 每片 **+2**（`CS` + `MISO`）⇒ 6 片共 **11 脚**（Dock 有 80 可用脚）。 | RTL/接口 | ⭐ 后续加键/加板的可行性 | ✅ **已改并实测**：`rtl/drivers/adc_farm.sv` 改为 **`generate for (g=1; g<N_ADC; g++)`** 扇出 + **`reg [23:0] miso_shift [1:N_ADC-1]`** 数组 + **新增 `sample_data_packed[N_ADC*12-1:0]`**（片 `i` = `[i*12 +: 12]`）。⭐ **端口向后兼容**：`sample_data0/1/2` **保留为别名** ⇒ ⛔ **既有 tb 与集成不用改一行**。<br>✅ **实测**：① `N_ADC=3`（丙的 `tb_adc_farm.sv` 原样）**PASS**；② 临时 tb `N_ADC=6` **PASS**（24 `sample_valid`、3 帧、**6 片数据 0 不一致**，临时 tb 已删）；③ **全量回归 25/25 通过**。⚠️ **`N_ADC=1` 未实测**（`miso_shift[1:0]` 为空数组，建议单片直接用 `mcp3208_scanner`）。 |
| **K-86** | ✅ **`oscillator_bank.v` 的 `TIMBRE_W` 只有 1 bit ⇒ "四大件"与"Looper 一层一件乐器"都做不出来**（2026-09-20 复核队友代码时发现） | 事实：`rtl/w3b/oscillator_bank.v` 第 13~14 行 `parameter TIMBRE_N = 2, TIMBRE_W = 1` ⇒ ⚠️ **只能选 2 种音色**。而：① ⭐ **四大件**（`BASS`/`GUITAR`/`PIANO`/`PAD`，见 `files/20-代码/音色设计.md` §一之二）需 **4 种** ⇒ `TIMBRE_W=2`；② ⭐⭐ **Looper"一层一件乐器"**（三层同时播三个音色，见 `K-82`）需 **≥3 种** ⇒ 同样 `TIMBRE_W=2`。⚠️ 另：`wavetable_bank.v` 目前**只挂一块 pROM**（`ip/wavetable_sine_rom_ip/`，512×16 正弦）⇒ 4 音色 × 2 表（soft/hard）**需要更多表数据**。 | RTL（乙） | ⭐ **四大件音色、Looper 的多层多音色** | ✅ **已改参数（2026-09-20）**：`TIMBRE_N: 2→4`、`TIMBRE_W: 1→2`（⭐ **只有一个引用点**：`timbre_id_i` 端口，自动随参数加宽）。<br>⭐ **验证**：全量回归 **25/25** 通过（`tb_w1_interfaces` 传 `1'b0` 仍合法，零扩展）。<br>⚠️ **仍未做（留给后续）**：① ~~`wavetable_bank.v` 只有**一块正弦 pROM** ⇒ 四大件的 4 音色 × soft/hard **表数据待补**（`T31b`）~~ ✅ **已补（`wavetable_bank.v` 的 `T31b generated ROM` 头注释）**：⭐ 4 音色 × 1024 点 × soft/hard，共 **10 张 pROM** 全部内嵌；② ⚠️ `timbre_id_i` 需**由 voice 锁存值驱动**（`K-82` 的"每 voice 属性"）—— 等 `note_manager`/`oscillator_bank` 去桩实装时一起做 |
| **K-87** | 🔴⭐⭐ **变异测试把"锚点找不到"当成 PASS ⇒ 一个模块可以静默失去全部回归保护**（2026-09-20 发现并修，**我自己引入的**） | **现象**：`mutation_test.ps1` 跑完打印 `PASS: every injected defect was caught`，但摘要里有 **`M21/M22 skipped -- anchor not found`**。⚠️ **根因**：脚本的 `$leaks` 只统计 `Caught -eq $false`，而 `skipped` 的 `Caught` 是 **`$null`** ⇒ ⛔ **不计入任何失败** ⇒ 打印 PASS。<br>**为什么会 skipped**：我 2026-09-20 把 `adc_farm.sv` 的 `N_ADC` 参数化（支持 5~6 片），**M21/M22 的 `find` 锚点指向被替换掉的写死代码**（`assign adc_cs_n[1] = ...` / `miso1_shift`）⇒ **锚点永久失配**。<br>🔴 **真正的危害**：`adc_farm` —— **队友新落地、我又改过**的模块 —— **在无任何变异体守着的情况下，被测出"变异测试全绿"**。⚠️ 这直接**让"变异测试全绿"这个结论失去意义**（同 `K-56` 家族：判据有效性是最底层前提）。 | 验证方法论 | ⭐⭐ **整个验收体系的可信度** | ✅ **已修（2026-09-20）**：① **M21/M22 锚点重新指向参数化后的代码**（`assign adc_cs_n[g] = adc_cs_n[0];` / `assign sample_data1 = sample_data_packed[23:12];`）⇒ 两个变异体**重新 RED（caught）**；② ⭐⭐ **脚本把 `skipped` 也算失败**（新增 `$skipped` 计数 + `exit 4` + 醒目告警"a skipped mutant guards NOTHING"）；③ 脚本头部加 NOTE 说明。⭐ **实测**：故意把 M21 锚点改坏 ⇒ **`FAIL: 1 mutation(s) were SKIPPED` + exit 4**（⛔ 不再打印 PASS）；全量 **22/22 caught、0 skipped、exit 0**。<br>📌 **纪律（新增）**：**改了变异体所指向的 RTL ⇒ 必须在同一个提交里重指锚点**；⛔ **并且"跑变异测试"不能只在收尾时做** —— ⚠️ 我这次是**推送时只跑了全量回归（25/25）而没跑变异测试**，所以没发现 |
| **K-88** | ⚠️ **`rtl/w3b/` 有三个模块是【空桩】，但已在 `Gowin2026.gprj` 里**（2026-09-20 审查队友代码时发现） | 三个模块的输出**全部接 0**、无任何功能逻辑：<br>· `oscillator_bank.v`（第 37~40 行）：`osc_sample_bus_o = 0`、`osc_valid_o = 0`<br>· `tdm_render_mixer.v`（第 26~28 行）：`dry_valid_o = 0`、`dry_sample_o = 0`、`deadline_fault_o = 0`<br>· `test_mode_ctrl.v`（第 30~34 行）：四个输出全 0<br>⚠️ 三者的注释都自称 **"W1-1 interface skeleton only … arrive later"** ⇒ ⭐ **属诚实的 WIP 标注**，⛔ 不是隐瞒。<br>⚠️ 但两个后果要记：① 它们**已被收进 Gowin 工程** ⇒ **当前综合产物是"32 voice 全哑"**；② ⭐⭐ **`test_mode_ctrl` 是空桩，而 Test Mode 是"评分必需"**（决赛现场会复测）⇒ 该功能**当前不存在**。 | RTL + 文档 | ⭐ 综合产物能否出声；⭐ **Test Mode 的交付缺口** | 🟡 **部分解决（2026-09-20）**：① 三者的"未实现"状态**已由代码注释诚实标注**，✅ 无需纠正；② ✅ **文档侧已更正** —— `分工.md` 曾把它们与真正落地的 `voice`/`adsr` 并列写成"已落地整套 `rtl/w3b/`"，现已明确区分"**可工作的**"与"**空桩**"；③ ⭐ **`test_mode` 缺口已单独跟踪** ⇒ 列入第二周 **`T43`（🔴 必做）**；④ ⭐ **`oscillator_bank`/`tdm_render_mixer` 去桩**列入 **`T55`/`T56`**（第二周 C 组"接通出声链"） |
| **K-89** | ✅ **`adc_farm` 的"兼容别名"是无条件的 ⇒ `N_ADC<3` 时越界读出 X**（2026-09-20 审查时发现，**我自己引入的**） | 事实：为让既有 tb 不改一行，加了三条别名：`sample_data0/1/2 = sample_data_packed[11:0]/[23:12]/[35:24]`。⚠️ 但 `sample_data_packed` 的宽度是 **`N_ADC*12`** ⇒ `N_ADC<3` 时**索引越界**。<br>⭐ **实测（临时 tb，`N_ADC=2`）**：`sample_data2 = xxx`（X）；`packed` 只有 24 bit，而别名要读到 bit 35。<br>⚠️ `N_ADC=1` 时 `sample_data1`/`sample_data2` **全越界**。 | RTL | ⚠️ **`N_ADC` 是公开参数** —— 别人设 2 就会拿到 X | ✅ **已修（2026-09-20）**：别名改为 `generate` 保护 —— 固定 3 片宽的 `sample_data_alias[35:0]`，`g < N_ADC` 时接 `sample_data_packed[g*12 +: 12]`，**否则接 `12'd0`**（⛔ 不越界）。<br>⭐ **实测**：`N_ADC=2` ⇒ `data2 = 000`（原 `xxx`）、`data0/data1` 正常 ✅；`N_ADC=3` 仍 PASS；⭐ **全量回归 25/25** |
| **K-90** | ⚠️ **采集链三模块（`adc_farm`/`calib`/`debounce`）不在任何 Gowin 工程里 ⇒ 从未被综合过**（2026-09-20 审查时发现） | 事实：`Gowin2026.gprj`（主工程）与 `bringup/synth_check.gprj`（队友的综合自检工程）**都不含**这三个文件。<br>⇒ ⭐ **它们只有仿真证据，没有综合证据**（`K-46`："被解析 ≠ 被综合"）。<br>⚠️ 另：主工程**含 3 个空桩**（`oscillator_bank`/`tdm_render_mixer`/`test_mode_ctrl`）⇒ **当前主工程综合产物是"32 voice 全哑"**。 | RTL + 工程 | ⚠️ 采集链能否真的综合进 60K；⚠️ 资源占用未知 | ✅ **已解决（2026-09-21，`T47`）**：三模块（+其依赖 `mcp3208_driver`/`scanner`）已加进 `bringup/synth_check.gprj`，并在 `synth_check_top.v` 里**真的例化**（⛔ 只登记不算，见 `K-46`）。<br>⭐ **实测**：`gw_sh bringup\synth_check.tcl` **exit 0**、**0 ERROR**、20 个模块**全部 `Compiling module`**（含 `calib`）。<br>⭐ **资源占用（60K：59904 LUT / 59904 FF / 118 BSRAM / 118 DSP）**：<br>· `adc_farm` **120 FF / 124 LUT**（含 3×`sync_input` + `scanner` + `driver`）<br>· `calib` **320 FF / 261 LUT / 1 DSP**<br>· `debounce` **146 FF / 267 LUT**<br>⇒ 采集链合计 **≈586 FF / 652 LUT / 1 DSP** = **1.0% FF / 1.1% LUT / 0.8% DSP** ⇒ ✅ **完全放得下**（与 `FPGA平台与资源评估.md` §3.6 的"采集链 ~1500 LUT"粗估同量级）<br>⚠️ **顺带抓出 `K-91`**（`calib` 根本没过综合）—— ⭐ **这正是 `T47` 的价值：不做这次综合，`calib` 会一直"仿真全绿、上板全废"** |
| **K-91** | 🔴⭐ **`calib.sv` 用了 SystemVerilog 带宽度强制转换 `N'(expr)` ⇒ Gowin 报 `EX3863` 并把【整个模块丢弃】**（2026-09-21，`T47` 一跑就抓到） | **现象**：把 `calib.sv` 加进工程跑综合 ⇒ <br>`ERROR (EX3863) : Syntax error near '''`（第 90/93/137 行，共 4 处）<br>`ERROR (EX3928) : Module 'calib' is ignored due to previous errors`<br>⇒ ⭐ **`calib` 完全没进综合**，`synth_check` 直接失败。<br>**根因**：源码里写了 4 处 SV 专有构造 —— `24'(FULL)` / `IW'(ITER)` / `PW'(FULL)` / `DW'(FULL)`。⭐ **Gowin 把 `.sv` 登记成 `type="file.verilog"`**（见 `Gowin2026.gprj` 注释），即**按 Verilog-2001 子集编译**。<br>⚠️⚠️ **最坑的地方**：**iverilog 接受这些写法** ⇒ ⭐ **仿真 100% 全绿**（`tb_calib` 一直过），**只有跑真综合才暴露**。<br>⚠️ 同一个坑 **`tlc5916_driver.sv` 里已经记过一次**（`longint'()` 在 Gowin 不可用，见该文件第 74~76 行）—— 但 `calib.sv` 又踩了。 | RTL + 工具链 | 🔴 **`calib` 能否综合** ⇒ ⭐ **采集链能否上板**（标定是力度/霍尔读数的前提）；⭐ 更深一层：**"仿真全绿"能不能当"能上板"的判据** | ✅ **已修（2026-09-21）**：把 4 处强制转换改成 **Verilog-2001 等价写法**（⛔ 纯语法、**零行为变化**）：<br>· `24'(FULL) << 8` → `localparam [23:0] DIVIDEND = FULL << 8;`<br>· `IW'(ITER)` → `localparam [IW-1:0] ITER_CNT = ITER;`<br>· `PW'(FULL)` / `DW'(FULL)` → `localparam [PW-1:0] FULL_EXT = FULL;` / `localparam [DW-1:0] FULL_CODE = FULL;`<br>（⚠️ 顺带发现：⛔ **不能对 `integer` 参数做位选** —— `FULL[DW-1:0]` 在 Verilog-2001 同样非法 ⇒ 必须先落成有宽度的 `localparam` 向量）<br>⭐ **验证**：① `gw_sh` 综合 **exit 0**、`Compiling module 'calib'` ✅；② **全量回归 25/25**（`tb_calib` 仍全过 ⇒ 行为等价）；③ 变异体 **M20 锚点已重指**（见下）。<br>📌 **纪律（新增，与 `K-87` 同族）**：**`.sv` 文件里 ⛔ 不要用任何 SV 专有构造**（强制转换 `N'()` / `longint` / `logic` / `always_ff` / `typedef` / `interface` …）；⭐ **判据 = 必须真的跑过一次 Gowin 综合** —— ⛔ "iverilog 过了"不算。<br>📌 **并且**：改了 `calib.sv` ⇒ ⭐ **M20 的锚点当场失配**（`skipped`）⇒ ✅ **已按 `K-87` 纪律在同一批里重指**（`quo_r <= 24'(FULL) << 8;` → `quo_r <= DIVIDEND;`）。<br>⭐ **`K-87` 的 `exit 4` 机制当场生效**：第一次重跑变异测试打印的是 **`FAIL: 2 mutation(s) were SKIPPED` + exit 1**，⛔ **不再静默 PASS** |
| **K-92** | ⭐ **`note_manager` 比冻结表多两个输入端口**（`env_active_i` / `env_level_i`）—— `T54` 落地时的**必要补充**（2026-09-21） | 事实：`files/20-代码/RTL代码结构与接口规划.md` §2.6 的 `voice_manager` 端口表**没有**这两个输入；⚠️ 但**同表** `envelope_bank` 的 `env_active_o` 注明「→ **manager**/status」⇒ ⭐ **原设计本意就是要回给 manager**。<br>⚠️ 为什么必须有：抢占顺序②是"**已 Release 且电平最低**"（同文件 §2.6 末段）—— ⛔ **不给电平就无法实现**；而不给 `env_active` 就要在 `note_manager` 里**复制一份 ADSR 状态**（⇒ 两份状态必然漂移）。 | RTL + 接口 | ⭐ 抢占策略能否正确实现；⚠️ 冻结表与代码的口径一致性 | ✅ **已按冻结表原意补上**（⛔ **不改任何既有端口名/宽度**）⇒ 对 `W3接口冻结表.md` §三 的两条通路（事件/参数）**零影响**，队友的 tb 不用改。<br>📌 **待办**：⭐ **把这两个输入补进 `RTL代码结构与接口规划.md` §2.6 的端口表**（⚠️ 该文属队友文档，**须作者同意** ⇒ 与 `K-34` 一并提） |
| **K-93** | ⭐⭐ **`AXIS_W=4` ⇒ 最多 16 个不同轴位，而 `POLY_TARGET=32`** —— "32 复音"**按不出来**（2026-09-21 `T54` 验收时发现） | 事实：`AXIS_W=4`（16 轴）是硬件决定（16 个霍尔键位）；而 `POLY_TARGET=32`。<br>⚠️ 后果：① ⭐ **单靠键盘最多同时响 16 个音**（每个轴位只能占一个 voice）⇒ **"32 复音"的演示不能靠键盘**；② 抢占的"占满 32"**在 tb 里根本构造不出来**（我因此把抢占判据挪到 `POLY_TARGET=4` 的小实例上验）。<br>⭐ 但这**不是缺陷** —— `POLY_TARGET=32` 的余量是给：**Looper 3 层**（每层独立事件流）+ **专用 voice**（节拍器/鼓机）+ **Release 尾巴重叠**（旧音未衰完、新音已起）。 | RTL + 验证 | ⭐ **"复音 ≥32"这条线怎么向评委证明**；⭐ 抢占判据的**可构造性** | ✅ **已澄清（2026-09-21）**：① 抢占判据**已挪到 `POLY_TARGET=4` 小实例**上验（按 4 个即占满 ⇒ 可构造），⭐ 实测通过；② ⭐ **32 复音的证明应走 `T43` Test Mode**（`test_mode_ctrl` 直接给 N 路不同频率的 gate，⛔ 不经过 `AXIS_W` 限制）—— 这正是"评分必需"那条的实现路径；③ ⚠️ 已写进 `T54` 证据文档 §四 的注释 |
| **K-94** | 🔴⭐ **`sim/tb_all.ps1` 跑 tb 时【没有任何超时】⇒ 一个 tb 挂死会让整套验收永久静默阻塞**（2026-09-21，**用户察觉"是不是卡住了"才发现**） | 事实：核心那行是**裸的** `& $vvp $vvpFile`（⛔ 无超时）。<br>⚠️ **三层危害**：① 单个 tb 挂死 ⇒ 永不返回；② ⭐ **回归器永久静默阻塞** —— **没有输出、没有报错、退出码也没有**；③ 🔴 **变异测试要跑 N 遍回归** ⇒ 某个变异体让 tb 死循环 ⇒ **整套变异测试永远跑不完**，而**看起来只是在慢慢跑**。<br>⚠️ 最危险处：**它与"正常慢"无法区分** —— 我当时的排查动作是"取两次 `vvp` 的 CPU 时间看是否增长"，那只是**人的临场判断**，⛔ 不能作为自动化验收的一部分（同 `K-87` 家族：**验收工具自身失效却无人察觉**）。<br>⚠️ 全仓 **26 个 tb 里有 12 个没有看门狗**。 | 验证工具 | 🔴 **整个项目的验收能否可信地跑完** | ✅ **已修（2026-09-21）**：`Start-Job` 后台起 + `Wait-Job -Timeout`（默认 **120 s**，可用 `-TimeoutSec` 调）；超时则 `Stop-Job` + **杀掉残留 `vvp`** + ⭐ **判该 tb 失败**（⛔ 不是通过）。<br>⚠️ **两个实现坑**：① ⭐ **`Start-Job` 里拿不到子进程退出码** ⇒ 判定**必须靠日志里的 `FAIL:` 行**（与既有 `$failRx` 口径一致）；② 超时后要**清残留 `vvp`**，否则它继续吃 CPU 拖慢后续 tb。<br>⭐ **实测**：故意造一个 `wait(1'b0)` 的挂死 tb ⇒ **20 s 就报 `FAIL: TIMEOUT after 20 s` 并判失败**（⛔ 不再永久卡住）；全量回归 **26/26** 不受影响。<br>📌 **纪律（新增）**：⭐ **任何"跑外部进程"的验收脚本都必须有超时**；⭐ **`skipped`/`timeout`/"没有结论" 一律算失败**（同 `K-87`/`C29`）。<br>⚠️ 遗留：**12 个 tb 自身仍无看门狗**（靠回归器的外部超时兜住）⇒ ⭐ 已列入 `T64`（把看门狗补进 tb 模板） |
| **K-95** | ⭐ **`oscillator_bank` 的颤音是"共享绝对偏移"，且同 voice 两个 lane 的失谐未实装**（2026-09-21 `T55` 落地时的**有意取舍**，⛔ 不是缺陷） | 事实：① **颤音** —— 冻结表 §三 说"颤音波形由 W3b 内部 LFO 生成，推子只给深度与速率"。本模块用**一个共享乘法器**算 `vib_off = VIB_REF_INC × vibrato_mod >> 15`，**64 个 lane 加同一个绝对偏移**（⛔ 不是按各自基频比例）。⚠️ 后果：**低音颤音幅度（音分）比高音大**。<br>② **失谐** —— `base_phase_inc_i` 是**每 voice 一份**（冻结表 §二："`phase_inc` 是每振荡器一个，voice 内多挂几个不动接口"）⇒ ⭐ **同 voice 的两个 lane 拿到相同 `phase_inc`** ⇒ 它们**同相叠加**，⛔ **没有失谐/加厚效果**。 | RTL + 接口 | ⭐ 颤音的听感自然度；⭐ "每 voice 2 个振荡器"的**加厚效果**是否算达成 | ⚠️ **已知取舍，待定**：<br>· 颤音"按比例"需要**每 lane 一个乘法器 = 64 DSP**（占 60K 的 **54 %**）⇒ ⛔ 不可接受。⭐ 正确做法是 **TDM 复用同一个乘法器**（64 拍算完 64 个 lane，帧内余量 15×）—— ⭐ **已列入 `T65`**。<br>· 失谐：⭐ 两条路 —— ① `test_mode` 覆盖（已在 `T55` tb 里验过通路可行）；② ⭐ **给 `oscillator_bank` 加一个 per-lane detune 表**（编译期常量，~64×16 bit = 1 kbit，**零 DSP**）—— ⭐ **已列入 `T65`**。<br>📌 两条都**不影响**"64 个独立振荡器"这条评分主体（相位累加器本来就是每 lane 独立的） |
| **K-96** | 🔴⭐ **自检顶层把 `voice_active_i` 写死成常量 ⇒ 综合器把 63 个未激活 lane 的相位寄存器整块优化掉 ⇒ "64 个独立振荡器"这条评分证据当场消失**（2026-09-21，`T55` 加进综合自检时**实测**抓到） | **现象**：`oscillator_bank` 在综合报告里只有 **1069 个寄存器**，而 ⭐ **光 64 lane × 32 bit 的相位累加器就要 2048 FF** ⇒ 明显不对。检查网表：`gen_lane` 只展开了 **2 个实例（0..1）**，⛔ **不是 64 个**。<br>**根因**：我在 `synth_check_top.v` 里为了"省事"把 `voice_active_i` 写成 `{{(POLY_TARGET-1){1'b0}}, 1'b1}`（**只有 voice0 活跃**）⇒ ⭐ 其余 63 个 lane 的 `phase_q` **恒等于复位值、永不改变** ⇒ **综合器把它们全部常量折叠掉了**。<br>🔴 **危害极大**：⭐ `K-83`/`K-84` 明确"**吞吐量 = 同时可闻的独立振荡器数 × 采样率**"，而 ⭐ **评委要翻代码/报告确认"独立"** —— 报告里数不出 64 份相位寄存器，**这条评分证据就没了**（⚠️ 而且仿真侧**完全正常**，因为仿真不做这种优化）。 | RTL + 验证 + **评分** | 🔴 **"64 个独立振荡器"能否被证明**（评分主体）；⭐ 更深一层：**"自检工程"本身会不会把要证明的电路优化掉** | ✅ **已修（2026-09-21）**：把 `voice_active_i` / `base_phase_inc_i` **引到自检顶层的输入**（⛔ 不写常量）⇒ 综合器**无法常量折叠**。<br>⭐ **实测**：`oscillator_bank` 寄存器 **1069 → 3657**；网表里 `gen_lane` 展开 **2 → 64 个实例（0..63）** ⇒ ✅ **"64 个独立振荡器"现在可机械核验**。<br>📌 **纪律（新增）**：⭐ **凡是"要用来证明某事"的电路，⛔ 不要在自检顶层把它写死/接常量** —— 综合器会**合法地**把"永不变化的寄存器"优化掉。⭐ 判据 = **综合报告里的寄存器数要对得上手算值**（本例：64×32=2048，实际 3657 含其它状态）。 |
| **K-103** | 🔴🔴 **`T57` 接通出声链后，交付顶层时序崩了：`Actual Fmax` 从 55.96 MHz 掉到 8.424 MHz、1408 个 setup 违规**（2026-09-21，`top.v` 集成后跑 `gowin_build.ps1` 发现） | **现象**：`sim/evidence/gowin_m0_timing.txt` ⇒ `Numbers of Setup Violated Endpoints = 1408`、`Actual Fmax = 8.424 MHz`（⚠️ 而我们**只有 50 MHz** 可用）。<br>**根因（已定位到模块级）**：25 条最差路径**全部**落在 `g_sound.u_note_manager` —— 典型一条：<br>`age_r[31]_2_s1/Q` → `phase_r[4]_17_s0/CE`，**slack = −98.704 ns**、**Data Delay = 118.474 ns**。<br>⭐ 机制：我的 `note_manager` 把**三级候选选择**（① 池内空闲 → ② Release 且电平最低 → ③ 年龄最老）写成**一整条组合优先级链**，每个循环都要扫 **32 个 voice**；而它的结果（`sel_valid`/`sel_idx`）又直接驱动 **32×32 位 `phase_r` 的时钟使能** ⇒ ⭐ **一级组合逻辑里塞了 32×(3 级比较) + 32 路 CE 译码** ⇒ 延迟 118 ns。<br>⚠️ 之前没发现是因为：`note_manager` 只进过 `synth_check`（**只跑综合、不跑 PnR**）⇒ ⛔ **综合通过不代表时序收敛**（`K-63` 的又一次印证）。 | RTL + 时序 | 🔴🔴 **交付顶层能否在 50 MHz 收敛** ⇒ ⭐ **直接决定板子能不能用**（不收敛 = 上板必错） | ✅ **已修（2026-09-21，`T66`）**：把候选选择改成**多拍流水** —— ⭐ **每拍只考察一个 voice**（32:1 mux + 一级比较 ≈ 2~3 级），扫完 32 拍再提交。<br>⭐ **为什么加延迟是免费的**：`adsr` 的 `gate` **只在 `sample_tick_i` 被采样**（每 **1024 拍**一次）⇒ 只要在**一帧内**完成，⭐ **`gate` 生效时刻一个采样拍都没变** ⇒ 端到端延迟仍 ≤1.233 帧。<br>⭐ **实测（`gowin_build.ps1`，含 PnR）**：**0 setup 违规、0 hold 违规、`Actual Fmax` = 58.610 MHz**（⚠️ **比崩之前还高**）、TNS 0；⭐ **LUT 14097 → 12019**（深组合链反而更费资源）；FF 5464 / BSRAM 1 / DSP 1。回归 **29/29**。<br>⚠️ **连带契约变更**：冻结表 §四 `note_manager` 由 `≤ 4 拍` → **`≤ 34 拍`**（⛔ 端口一字未改 ⇒ 队友 tb 只需改等待拍数）。⭐ **已写进 `W3接口冻结表.md` §四** |
| **K-104** | ⭐ **`synth_check` 只跑综合（`run syn`），⛔ 不跑布局布线 ⇒ 它【看不见时序问题】**（2026-09-21，`K-103` 暴露出来的方法论缺口） | 事实：`bringup/synth_check.tcl` 里只有 `run syn`。⚠️ 它证明的是"**可综合性 + 资源占用**"，⛔ **不是时序收敛**（脚本头部其实写了这句，但**我加 `note_manager`/`oscillator_bank`/`tdm_render_mixer` 时只看了"有没有 ERROR"，没意识到它根本不查时序**）。<br>⇒ 🔴 **后果**：`K-103` 那个 8.4 MHz 的问题，在 `synth_check` 里**完全看不出来**，直到 `T57` 把它们接进交付顶层跑 `gowin_build.ps1`（含 PnR）才暴露。 | 验证方法论 | ⭐ **"模块级自检"能否替代"顶层时序验收"** | ⚠️ **已知边界**：⭐ 纪律 = **新模块落地时必须接进 `Gowin2026.gprj` 跑一次 `gowin_build.ps1`**（含 PnR），⛔ 不能只跑 `synth_check`。⭐ 已列入 `T67`（把这条写进"模块落地清单"）。📌 **`synth_check` 通过 ≠ 时序收敛** —— 资源/可综合性与时序是**两份证据**（同 `K-91` 家族） |
| **K-105** | 🔴⭐ **变异测试把"变异体根本编译不过"当成了"判据抓到了"** ⇒ **一个判据都没跑过的变异体显示绿色**（2026-09-21，重指 `M23` 锚点时发现） | 事实：判定只有一行 `$caught = ($exit -ne 0)`。⚠️ 而**一个语法错误的变异体也会让回归非零退出** ⇒ ⭐ **"编译失败"被当成"被抓到"**。<br>🔴 **危害不是单个变异体** —— 它让 ⭐ **"变异测试全绿"这个"整套判据有效性"的证据，可以【由编译错误刷出来】**。<br>**怎么发现的**：`M23` 的锚点**只是目标行的前缀** ⇒ 替换后留下 `1'b1; & ~hold_mask[mg];` ⇒ 语法错 ⇒ ⚠️ 而它**显示为 caught**。 | 验证方法论 | ⭐⭐ **整个"判据有效性"证据的可信度** | ✅ **已修（2026-09-21）**：**区分两类非零退出** —— ① 输出含 `syntax error`/`unable to` **且没有 `FAIL:` 行** ⇒ ⭐ **判该变异体【无效】**（`Caught = $null`，与"锚点找不到"同级别，⛔ **不是通过**）；② 有 `FAIL:` 行 ⇒ 才算真被抓到。<br>⭐ **实测**：`M23` 修正锚点后 **CAUGHT（7 个 FAIL）**。<br>📌 **纪律（新增）**：⭐ **变异体的前置条件是"它能编译"，⛔ 不是"它让回归变红"** —— 先证明变异体本身是活的 |
| **K-106** | ✅ **`note_manager` 的事件 FIFO 深度不足 + 溢出【静默丢弃】⇒ 可能造成【挂音】**（2026-09-21 `T66` 重构后复盘发现；⭐ **同日修复**） | **事实（三个叠加）**：<br>① ⭐ **排空一个事件 = ~35 拍**（`ST_IDLE(1) + ST_DECIDE(1) + ST_SCAN(32) + ST_COMMIT(1)`）⇒ 0.7 µs/事件；<br>② ⭐ **`FIFO_DEPTH = 16`** ⇒ 排空全部 = **560 拍 = 11.2 µs**；<br>③ 🔴 **溢出时静默丢弃** —— `fifo_push = note_valid_i && !fifo_full`，**无任何指示**。<br>**最坏突发**：⭐ **16 键同时按 + 节拍器 1 + 鼓机 1 = 18 个事件** ⇒ **丢弃 2 个**。<br>🔴 **真正的危害不是"丢一个音"，而是【挂音】**：⚠️ 若被丢的是 **`note_off`** ⇒ ⭐ **那个音永远关不掉** —— 正是 `Looper详细设计.md` **`T38` 专门要防的失效模式**。⚠️ 且**丢哪个是不确定的**（取决于到达顺序）。<br>⚠️ **而且这条路径从未被验证**：`tb_note_manager.sv` 里 ⛔ **没有任何 `fifo`/`overflow` 字样**。 | RTL + 验证 | ⭐ **16 键同时演奏 + 自动功能** 时是否丢音/挂音；⚠️ **Looper 多层重放的事件吞吐** | ✅ **已修（2026-09-21，用户拍板"都加"）** —— ⭐ **四项全做**：<br>① ⭐ **`FIFO_DEPTH: 16 → 32`**（`32 ≥ 18`，余量 14）⇒ ⭐ **降低丢音【概率】**；<br>② ⭐⭐ **加溢出指示（3 个新端口）**：`event_lost_o`（**sticky**）+ `event_lost_cnt_o[7:0]`（**饱和**计数）+ `event_lost_clr_i`（读走清零）⇒ ⭐ **让丢音【可被发现】**；<br>③ ⭐ **补 tb**：`tb_note_manager.sv` 新增 `section 10`（15 条判据，含**反证基线**与**饱和**验证）；<br>④ ⭐ **加变异体 `M45`–`M48`** 守卫上报路径（静默化 / 不计数 / sticky 不置位 / 取消耗和）。<br>⭐⭐ **一条必须记住的概念**：⭐ **①和②【正交】，⛔ 谁都不能单独"不丢音"** ——<br>· ① 只是**把墙往后挪**（超过 32 照样丢）；<br>· ② **不能阻止**丢，只让丢**可见**；<br>· ⛔ **"永不丢音"不存在**（队列有限 + 上游无限 ⇒ 数学上必然溢出）。<br>⇒ ⭐ **可接受的工程语义 = "要么不丢，要么丢了立刻知道"**。<br>⚠️ **本次改了端口（+3）⇒ 属接口变更**（冻结表 §〇 约定 5，须通知全员）。⚠️ 已有例化**不接新输入**仍合法（恒 0 ⇒ 只置位不清）。<br>⚠️ **副作用（已知且可接受）**：排空时间 560 → **1120 拍 = 22.4 µs**；⭐ **听感延迟不变**（`gate` 每 1024 拍采样一次，22.4 µs 仍在一帧内）。<br>📌 **另记一条约束（仍然有效）**：⭐ **`note_manager` 的事件吞吐上限 ≈ 1 事件 / 0.7 µs** ⇒ ⚠️ **Looper 的每层配额（贝斯 2 / 吉他 8 / 钢琴 12）必须按这个上限校核**（`T36`–`T39` 时一起做）。<br>📌 **纪律升级（可复用）**：⭐ **任何"容量有限"的队列/计数器，都必须有【可观测的溢出指示】；且计数必须【饱和】而不是回绕**（⚠️ 回绕会把"丢了 256 个"显示成"丢了 0 个" —— **那是另一种静默**）。 |
| **K-108** | ⭐⭐⭐ **写"容量/计数"类判据时，⛔ 不要硬编码"我以为的算术值" —— 要写成【守恒不变量】**（2026-09-21 修 `K-106` 的 tb 时实测踩到） | **现象**：`K-106` 的 tb 我第一版写 `期望丢失数 = 灌入 12 − 深度 4 = 8` ⇒ 🔴 **实测 7，判据红了**。<br>⚠️ **第一反应是"RTL 有 bug"**，但逐拍追踪后真相相反：<br>· ⭐ **RTL 是对的** —— `fifo_cnt` 最大**精确到 4**（✅ 没有溢出覆盖）；<br>· ⭐ **是我的模型错了** —— FIFO 深度 4，但 **FSM 同时在排空** ⇒ 一次突发里能被吸收的**不止 4 个**。<br>🔎 **实测**：12 个背靠背事件 ⇒ **服务 5 个**（轴 0..4）+ **丢 7 个**（轴 5..11），`lost_cnt = 7` 完全正确。<br>⭐ **修法**：把判据从"**硬编码算术**"改成"**守恒不变量**"：<br>`灌入总数 = 被服务数 + 被丢弃数`（`12 = popcount(voice_gate) + event_lost_cnt`）<br>⭐ **它同时能抓两种真 bug**：① **静默丢**（丢了但不计数）② **重复计数**（计数比实际丢的多）。<br>⚠️ **连带发现（同样重要）**：守恒判据**必须等队列排空后再验** —— 突发刚结束时 FSM 还没分配（实测此刻 `popcount=0`）⇒ 过早验会**误报**。⭐ 即"**判据要打在稳态上，⛔ 不是过渡过程**"（同 `C33`）。 | 验证方法论 | ⭐ **判据本身的可信度**（同 `C21`/`C36`） | ✅ **已修**：判据改成守恒式 + 先 `settle` 再验；`tb_note_manager.sv` 的 `section 10` 现有 **15 条判据**，且打印真实拆分（`12 = 5 served + 7 lost`）。<br>📌 **纪律**：⭐ **"判据红了"不等于"被测有 bug"** —— ⚠️ 先问"**我算的那个数凭什么是对的**"（同 `C33`：先怀疑自己的时基/假设）。<br>📌 **推论**：⭐ **凡涉及"容量/并发/排空"的算术，人脑很容易漏掉"并发吸收"这一项** ⇒ ⭐ **一律写成守恒式**。 |
| **K-107** | 🔴⭐ **两个"自己造的坑"：① `beat_gen` 相位推进与出 tick 合并成一个条件 ⇒ 【自锁死、一个 tick 都不出】；② 上报的 `tick` 编号与 `tick` 脉冲【差 1】**（2026-09-21 新会话落地 `T32`/`P1` 时实测抓到） | **① 【自锁死】**：`wire do_tick = run_i & phase_carry;` 同时被用作**相位推进**的条件 ⇒ ⭐ **相位要靠进位才推进，而进位要靠相位推进才出现** ⇒ `phase_q` 永停 0。⚠️ **实测：120 000 clk 出 0 个 tick**；而 `transport_o` **已经拉高** ⇒ 表现像"没使能"，**极易误判成 tb 的问题**（本次绕了好几轮）。<br>⭐ **修法**：**相位无条件推进**（`wire phase_en = run_i;`），**进位只决定出不出 tick**（`do_tick = run_i & phase_carry`）⇒ 两者解耦。<br>**② 【off-by-one】**：`tick_cnt_q` 既当"上报值"又当"运行状态"，推进写在 `if (do_tick)` 里 ⇒ 上报比推进晚一拍 ⇒ 实测 `tick#1` 报 `tick_cnt=1`（应为 **0**）。⚠️ **连带后果**：`bar_start` 落在 `tick#3840`（应为 **#3839**）⇒ **小节边界与末拍错开一格，与鼓机/looper 对齐时就是错拍**。<br>⭐ **修法**：`tick_cnt_q` 表示"**下一拍将携带的编号**"，并用**独立输出寄存器** `tick_cnt_o_q` 在 tick 那一拍锁存**本拍自己的编号** ⇒ 严格同拍。<br>⭐ **修正后实测**：`beat` 间隔 **精确 960 tick**、落在 `tick_cnt` = 0/960/1920/2880，`bar_start` 与强拍同拍（3840 = 960×4）。<br>📌 **根因（方法论）**：两个坑都**不是**"语法错"或"跑不通"，而是**逻辑上自洽、仿真不报错、只在数拍时暴露** ⇒ ⭐ **必须靠"数间隔 + 数字段"的判据抓**，光看"有没有波形"永远抓不到。 | RTL + 验证 | ⭐ **整个音乐时基的正确性**（节拍器/鼓机/Looper 全依赖它） | ✅ **已修（2026-09-21，`T32`/`P1`）**：`rtl/w3c/beat_gen.v` + `tb/w3c/tb_beat_gen.sv` 已落地；⭐ **回归 30/30**、⭐ **综合实测 `Compiling module 'beat_gen'`**（⛔ 不是只有 "Analyzing"，见 `K-46`/`K-91`）。<br>⭐ **已加变异体 `M41`–`M44`** 守卫这四点（自锁 / tick 率 / 相位在 bar 边界停 / 上报编号差 1）。 |
| **K-109** | 🔴⭐⭐ **"脉冲"与"脉冲携带的数据"没有同拍锁存 ⇒ 消费者读到【上一拍/下一拍】的数据**（2026-09-22 写 `metronome` 时实测抓到） | **现象**：节拍器**强拍永远发不出去**（永远响弱拍音），⚠️ 而**计数却是对的**（`accent_cnt` 数到了 2）⇒ 🔴 表现为"**计数器说发了强拍，耳朵听到弱拍**"，⭐ 极难查。<br>**根因**：`evt_valid_o` 是**寄存器**（`evt_valid_o <= fire`），而数据字段 `evt_phase_inc_o` 是**组合**的（`is_accent ? INC_ACCENT : ...`，跟着 `beat_i` 走）⇒ ⭐ **`valid` 比数据晚一拍**：消费者在 `valid=1` 那一拍读到的 `phase_inc` 已经是**下一拍（弱拍）**的值。<br>🔎 **实测证据（逐拍打印）**：<br>· `clk 63`：`beat=1, bar_start=1, inc=151183`（强拍 ✅）但 **`evt_valid=0`**<br>· `clk 64`：`beat=0, bar_start=0, inc=75591`（弱拍 ❌）而 **`evt_valid=1`** ✅<br>⭐ **修法**：把字段**也在同一拍锁存**（与 `valid` 同源、同拍），即 `evt_inc_r <= is_accent ? INC_ACCENT : INC_NORMAL;`。⚠️ 代价仅 ~40 FF。<br>⭐ **修正后实测**：`VALID` 那一拍 `inc=151183, vel=220`（**强拍载荷** ✅）、其余 `75591/140`。 | RTL + 验证 | ⭐ **所有"脉冲 + 携带数据"的接口**（事件通路/握手/valid-ready） | ✅ **已修 + 已守卫**：`rtl/w3c/metronome.v`；⭐ 变异体 **`M51`** 专门守这条（把载荷打回 `INC_NORMAL`）⇒ **caught**。<br>📌 **纪律（可复用）**：⭐ **"脉冲"与"脉冲携带的数据"必须同一拍锁存**；⚠️ **计数/状态对但输出错**是一类**特别隐蔽**的签名 —— ⭐ 此时要怀疑"**数据路径与 valid 路径不同拍**"。<br>📌 **同族**：经验库 `TROUBLESHOOTING` **77 号**（上报编号与脉冲差 1）/ `L68` 铁律 2 —— ⭐ **同一根因的第三次出现**（前两次在 `beat_gen`）。 |
| **K-110** | ⭐⭐⭐ **写判据时"怎么数那个量"本身就可能错 —— 而我连续错了三次**（2026-09-22 写 `tb_metronome` 时） | **现象**：`tb_metronome` 里"强拍间隔必须是 4 拍"这条判据**连续假失败三次**，每次都以为是 RTL 有 bug：<br>① **按 `bar_start` 电平分类** ⇒ 恒 0 个强拍。⚠️ 根因：`evt_valid_o` 晚一拍，采样时 `bar_start` **早已落下**（⭐ 这恰好**引出了 `K-109` 那个真 bug**）。<br>② 改成**数"中间的弱拍数"** ⇒ 得 **3**。⚠️ 根因：间隔是 **4 个事件**（3 弱 + 1 强），⭐ **我漏掉了那记强拍本身**。<br>③ 改成**事件序号差** ⇒ ✅ 正确（无歧义）。<br>⭐ **还有一条同类**：`perc_env_bank` 的 tb 里我断言"三个乐器同时在响"，⚠️ 但乐器 0 在**前一段 765 拍**里**已经衰完**了 ⇒ 应为 `4'b0110` 而非 `4'b0111`。 | 验证方法论 | ⭐ **判据本身的可信度**（同 `C21`/`C36`/`C44`） | ✅ **已修**：三条判据全部改成**结构性/无歧义**的写法。<br>📌 **纪律**：⭐ **判据连续假失败时，先怀疑"我的计数/分类方式"**，⛔ 不要直接改被测。<br>📌 **推论**：⭐ **凡"间隔/配对/并发"类的量，优先用【序号差】或【守恒式】** —— ⚠️ "数中间有多少个"这种写法**极易漏掉端点**。<br>📌 **同族**：`K-108`（守恒不变量）、经验库 `C44`、`TROUBLESHOOTING` **79 号**。 |
| **K-111** | 🔴⭐⭐ **两道"从未被触发的防御"与一个"无效变异体" —— `M50`/`M55` 连续 LEAK 暴露的方法论缺口**（2026-09-22 写 `T33` 时，变异测试抓到） | **背景**：`metronome`/`perc_env_bank` 的第一版 tb 全过，但变异测试报 **2 个 LEAK**。<br>🔎 **逐个查下去，两个 LEAK 是【完全不同】的原因**：<br><br>**① `M50`（`fire = fire_accent\|fire_normal` → `fire = beat_i`）**<br>· ⚠️ 第一反应：tb 只验了"**开机就是 `run=0`**"，没验"**跑起来再停**" ⇒ 补了 `stop_test`。<br>· 🔴 **补完仍然 LEAK** ⇒ 继续查 ⇒ 根因是：⭐ **`beat_gen` 在 `run=0` 时根本不 tick** ⇒ `beat_i` 恒 0 ⇒ **两种写法在 `run=0` 下行为完全相同** ⇒ 🔴 **`M50` 是【无效变异体】**（`C23`：不能改变行为的变异体不是有效变异体）。<br>· ⭐⭐ **更深的发现**：`metronome` 里的 `transport_i` 闸门是**防御性的**（`beat_gen` 已挡住）⇒ ⚠️ **这道防御从未被触发过** = **假安全**。<br>· ✅ **修法**：加 **DUT-B 直接驱动 `beat_i`**（⛔ 不经过 `beat_gen`）⇒ ① 防御**真的被验证** ② `M50` 变成**可被观测** ⇒ **caught**。<br><br>**② `M55`（`peak_r <= vel_peak` → `peak_r <= 0`）**<br>· 🔴 根因：⭐ **`peak_r` 当时只被写、从未被读** ⇒ 是**死状态** ⇒ 改它**不改变任何行为**（又一个无效变异体）。<br>· ⚠️ 而这暴露了一个**真的语义缺陷**：原实现用组合的 `vel_peak` 直接装载 ⇒ ⭐ **音还在响时拉力度滑杆，峰值会中途改变**（违反"起音时刻锁存"）。<br>· ✅ **修法**：改成 `load_r` + `level_r <= peak_r` ⇒ ⭐ ①`peak_r` **真的被读** ②"起音锁存力度"**成立且可测** ③ 补判据"**音符中途改力度，峰值不许变**" ⇒ **caught**。 | 验证方法论 + RTL | ⭐⭐ **"防御"与"判据"的有效性** | ✅ **已修**：`metronome.v`（`gate_direct` 直接驱动）+ `perc_env_bank.v`（`load_r` 真用 `peak_r`）+ 两条新 tb 判据。<br>📌 **纪律一**：⭐ **"变异体 LEAK"要先分两类** —— ① **判据没覆盖**（补判据）② **变异体本身无效**（⛔ 改判据也没用，必须**换锚点**或**先修 RTL 让状态真的被用**）。⚠️ 我第一反应只想到①，多绕了一轮。<br>📌 **纪律二**：⭐ **"防御性代码"若从不被触发，就等于没有** —— ⛔ 而且它会给出**虚假的安全感**。✅ 要么**证明它有效**（像 DUT-B 那样直接驱动），要么**删掉**。<br>📌 **纪律三**：⭐ **"只写不读"的寄存器是死状态** —— ⚠️ 它会让**指向它的变异体变成无效变异体**，从而**掩盖真实的语义缺陷**（本例：力度没锁存）。<br>📌 **同族**：`K-105`（编译失败当抓到）、`C23`（无效变异体）、`C36`（探针位置）、`K-108`/`K-110`。 |
| **K-112** | ⚠️⭐ **新增模块在"集成进交付顶层"之前【拿不到时序证据】—— 而 `synth_check` 工程**根本不可能**跑 PnR**（2026-09-22 实跑确认） | **事实（实测）**：<br>· ⭐ `synth_check_top` 把上百个信号引到端口（为了防综合器剪掉要证明的电路）⇒ 实测 **6396 个端口**<br>· 🔴 器件 GW5AT-60B（PG484）**只有 273 个可用 I/O** ⇒ `run pnr` 直接失败：<br>  `ERROR (PA2024): The number(6396) of ports exceeds the resource limit 273`<br>⇒ ⭐⭐ **结论：`synth_check` 是【只能综合】的工程，⛔ 永远无法布局布线。**<br>⚠️ **后果**：新模块（如 `metronome`/`perc_env_bank`）在**集成进 `top.v` 之前**，<br>只有"可综合性"证据（`Compiling module ...`），⛔ **没有时序证据**。<br>🔴 而 `K-104` 已经证明过这条路的危害：`note_manager` 就是这么藏了一个 **8.4 MHz** 的时序问题。 | 验证方法论 | ⭐⭐ **"新模块到底有没有时序证据"** | ⚠️ **这是【已知边界】，不是待修 bug**（`synth_check` 的设计目标就是"只验可综合性 + 资源"）。<br>⭐ **纪律（强化 `K-104`）**：<br>① ⭐ **新模块只有"进了 `top.v` 并跑过 `gowin_build.ps1`"才算拿到时序证据**；<br>② ⚠️ **在此之前，⛔ 不许说"这个模块验过了"** —— 只能说"**可综合性已验、时序未验**"；<br>③ ⭐ 交付时说清"**本次 PnR 覆盖到哪一层**"（本例：覆盖 `top.v`，⛔ **不含**当天新增的两个模块）。<br>📌 **与 `K-104` 的关系**：`K-104` 说"`synth_check` 不查时序"，本条**进一步**说明它**连查的机会都没有**（端口数超限）。<br>📌 **代价评估**：⚠️ 这意味着"新模块的时序风险**必然推迟到集成时**才暴露 ⇒ ⭐ 集成要**尽早**做，⛔ 不要攒到最后。 |
| **K-27** | ✅ **原理图入库了**（`files/10-硬件/原理图/`：`files/10-硬件/原理图/lefthand_board.pdf`+`.tel`、`files/10-硬件/原理图/righthand_board_A.pdf`+`.tel`） | ⇒ ⭐ **我们自己两块板的原理图与网表已可复核** ✅。⚠️ 仍未入库的是 **Dock/核心板的原厂原理图与规格书**（受 `.gitignore` 影响）—— 决定是否放入 `files/40-参考资料/` | ⬜ 部分解决 |
| **K-113** | 🔴⭐ **W3a 采集链的轴数必须【参数化到 4~6 片】—— 现状按 1~2 片落地，但接口⛔ 不得写死**（2026-09-23 用户拍板） | **需求（用户原话要点）**：⭐ **本轮先按【1 片 8 轴】落地；⭐ 最少会有 2 片；⚠️ 后续可能加到 4 片甚至 6 片** ⇒ ⭐ **必须做好参数化准备**。<br>⚠️ **三个必须一起参数化的量**：<br>① 🔴 **轴号 = `片号 × 8 + sample_ch`**（⭐ 依据 `adc_farm.sv` 的 `u_scan0`/`sample_ch`：多片**并行锁步**、`sample_ch` 是 **3 bit 的【片内】通道号**）⇒ ⛔ **单独用 `sample_ch` 当轴号会让多片互相覆盖**；<br>② 🔴 **`note_manager.AXIS_W = 4`（16 轴）** —— ⚠️ **1 片 = 8 轴 ✅ 放得下；2 片 = 16 轴 ⚠️ 刚好占满；4 片 = 32 轴 🔴 放不下**；<br>③ ⭐ **`calib` 是单片 8 通道**（`NCH = 8`）⇒ ⚠️ **每片要一份 `calib`**，⭐ 且**片数一变例化数就变**。<br>⚠️ **相关既有结论**：`K-85` 已把 `adc_farm.N_ADC` 参数化（支持 5/6 片、实测 `N_ADC=6` 通过）⇒ ⭐ **物理层已经准备好了，缺口在【语义层】**（`axis_map`/`event_extract`/`param_extract` 三个模块**尚未创建**）。<br>⚠️ **另一条已知边界**：`K-93` 已记录 `AXIS_W=4` ⇒ **单靠键盘最多同时响 16 个音**，"32 复音"要靠 `test_mode` 证明（⛔ 不靠键盘）。 | RTL + 接口 | 🔴 **采集链能否扩容到 4~6 片**；⭐ 直接决定 `axis_map`/`event_extract`/`param_extract` 的**端口宽度写法** | 🟡 **待做（2026-09-23 已定方向，代码未落）**：<br>① ⭐ **本轮按 1 片 8 轴落地**（`AXIS_W=4` 现成，⛔ 不动队友模块）；<br>② 🔴 **三个新模块的轴号一律写成参数化算式**（`axis_id = adc_idx * 8 + ch`），⛔ **不许写死**；<br>③ ⚠️ **升到 2 片只需改参数**（8→16 轴，仍在 `AXIS_W=4` 内）；<br>④ 🔴 **升到 4 片/6 片时必须先解决 `AXIS_W`**（4 的 `AXIS_W` 只够 16 轴）⇒ ⚠️ **改 `AXIS_W` 属改队友模块**（`note_manager`）⇒ ⭐ **须商量 + 重跑 PnR**（⚠️ `Fmax` 余量本来就不宽，见 `K-103`）。<br>⭐ **设计基线**：`files/20-代码/W3a采集链语义层设计草案-20260923.md` §六（D1/D2 待拍板项）。<br>📌 **本条的用法（用户要求）**：⭐ **后续要做的事都往本清单写；做完了就改状态并记录变化**（⛔ 不删行）。 |
| **K-114** | ⭐⭐ **"我们只能跑 480p"是【不用 PLL 那条铁律的推论】，⛔ 不是芯片能力上限 —— 1080p 能做，只要用【专给 TMDS 的 PLL】**（2026-09-23 用户提问引出，已复核） | **用户提问**："为啥别人的能跑 1080p 60 帧，我们只能跑 480p？真的没有板载高速时钟可以用吗？"<br>⭐ **答案：能跑，而且板载时钟资源不止一个 —— 但需要 PLL。**<br>**事实**：<br>① 🔴 **1080p@60 像素时钟 = 148.5 MHz**，板载主晶振 **50 MHz** ⇒ `148.5/50 = 2.97` **⛔ 不是整数** ⇒ **必须倍频**；<br>② ⭐ **整数分频下只有 640×480 可用**（`50/2 = 25 MHz` ≈ 25.175 MHz，误差 **0.70%**）⇒ ⭐ **"只能 480p"是这条的推论**；<br>③ ⭐ **器件有 8 个 PLL**（60K）；⭐ **官方自己就在用** —— `TMDS_PLL_60HZ.v` 写 `50 × 297 / 200 = 74.25 MHz`（标准 720p TMDS 时钟）；<br>④ ⚠️ 板上其它高速网络**不是给用户逻辑的**：`MS5351M`（`U7`，可编程、**官方定位是 SerDes 参考时钟**）、125 MHz 振荡器、`AB12 USR_CLK_IN`（在 `BANK9`，必须 1.5 V）⇒ ⭐ **`K-68` 已结论"继续用 50 MHz"**。<br>🔴 **关键澄清（本条的要点）**：⭐ 文档到处写"⛔ 不用 PLL"，⚠️ 但 **`K-41` 早已把准确边界定清** —— **禁的是"用 PLL 输出做【全设计系统时钟】"，⭐ ⛔ 不是"不能用 PLL"**；`代码总览图.md:256` 亦确认 **"✅ PLL 用于外设 / 相移时钟是正常的"**。⇒ ⭐ **专给 HDMI 像素时钟的 PLL 完全合规。**<br>⚠️ **但代价是真实的（`K-41` 要求）**：用 PLL ⇒ 必须留**活体见证**（心跳/UART 仍跑板载时钟）+ 三份构建报告 + 按手册算 `fVCO` + 对照实验（⚠️ 上上个项目**同一颗芯片**上 PLL 输出做全设计时钟 ⇒ **综合零 error、板子全死**）。 | RTL + 时序 + **评分（答辩加分项）** | ⭐ **HDMI 可视化分辨率**；⚠️ 与"添固表 §〇 约定 1（单时钟域）"的关系 | 🟡 **口径已澄清，⛔ 暂不实施（2026-09-23）**：<br>① ✅ **技术结论：1080p 可行**，路径 = **加一个只驱动 TMDS 的 PLL**，⚠️ **`K-41` 不禁止**；⚠️ **且 720p（74.25 MHz）与 1080p 是同一个 PLL 的活儿 ⇒ 成本几乎一样**（⭐ 真要升级建议一步到位）；<br>② 🔴 **但本轮⛔ 不做** —— ⭐ 理由：**(a)** 本周硬指标是 **"按琴键出声"（W3a）**，⚠️ 1080p 一个字都不沾；**(b)** `K-41` 的验证流程（活体见证 + 三份报告 + fVCO 核算）**不是改个参数**；**(c)** ⭐ **`产品形态决议清单.md` §九-3 已算过账** —— **串口屏（7 寸 1024×600）自带曲线控件、能承担波形显示**，结论是"**主体先只做串口屏，HDMI 后置**"；<br>③ ⭐ **`K-81` 合规红线仍然有效**（不变）：**可视化的"生成"必须在 FPGA 内完成**（`vis_tap` 输出**已算好的点**），⭐ 串口屏 / HDMI **只做搬运与显示**；<br>④ ⚠️ **若将来要做 1080p**：⭐ 必须先**重开**"添固表 §〇 约定 1"（单时钟域）⇒ ⚠️ **属集成层约定变更 ⇒ 要通知全员**。<br>📌 **口径修正**：`第二周计划-v4` §5.3 把"加 PLL"写成"**与约定 1 直接冲突**"，⚠️ 措辞**过强** —— ⭐ **准确说法是"与『全设计单时钟域』冲突，但可作为【TMDS 专用外设时钟】引入"**（同 `K-41`）。 |
| **K-115** | ⭐⭐ **变异测试的跑法纪律：小改动跑对应部分，收工/提交前跑全量 —— ⚠️ 但必须知道两种跑法【各自证明什么】**（2026-09-23 用户提出并拍板） | **起因**：⭐ 用户指出"改一点就全量跑 4 小时"不可持续（⚠️ 实测：**76 个变异体 × 每个跑全套 36 tb 回归 ≈ 3.9 小时以上**，21:12 启动到 01:03 仍未完）。<br>**⭐ 关键区别（⛔ 这是本条的要点）**：<br>· ⭐ **前端始终全量** —— 无论选几个变异体，**每个变异体都跑完整的 36 个 tb 回归** ⇒ ⭐ **"我的改动有没有弄坏功能"【始终】被全量覆盖**；<br>· ⚠️ **被裁剪的只是"变异体注入数"** —— 即"**回归还有没有能力抓住模块 X 的缺陷**"；<br>⇒ 🔴 **所以局部跑【不能】证明"别的模块的判据还有效"**（⚠️ 例如改了 `evt_merge` 却让 `play_seq` 的判据失效）⇒ ⭐ **这就是"提交前仍须全量"的硬理由**。<br>**⭐ 已有机制（⛔ 不用新写）**：`bringup/mutation_test.ps1` 支持 `-Changed`（按 git diff 自动挑）/ `-File <子串>` / `-Filter <ID>`。⭐ **实测**：改了 `top.v` ⇒ `-Changed` **精确选中 7 个**（M05/M08/M15/M18/M38/M39/M40，⛔ 无误选）；`-Filter M73` ⇒ **1 个 ≈ 3 分钟**。 | 验证方法论 | ⚠️ **开发迭代速度 vs 验收可信度**的平衡 | ✅ **已拍板并写入脚本头部（2026-09-23）**：<br>⭐ **纪律**：<br>① **迭代单个模块** ⇒ `-Changed` 或 `-File <模块>`；<br>② ⭐⭐ **收工/睡觉前** ⇒ **全量**（⚠️ 好处：它**最后一步会从干净 RTL 重跑一次回归** ⇒ ⭐ **第二天开工时证据是干净的**）；<br>③ 🔴 **提交/推送前** ⇒ **全量**（⭐ 见上方"两种跑法证明什么"）；<br>④ ⚠️ **改了共享文件**（`sim/tb_all.ps1` · `tb/models/*` · `tb/checkers/*` · `sim/evidence/*`）⇒ ⭐ **一律全量**；<br>⑤ ⚠️ **改了 `rtl/top.v`** ⇒ ⭐ **一律全量**（集成点）。<br>🔴 **两条安全前提（⛔ 违反会出事）**：<br>· ⭐ **启动全量前先 commit** —— ⚠️ 脚本**就地改 RTL 再还原**，若中途断电/被杀而**没有可回退点** ⇒ ⭐ **分不清"变异残留"还是"我自己的改动"**（同 `C38`）；<br>· 🔴 **跑的过程中 ⛔ 不要碰 `rtl/` `tb/`、⛔ 不要 `git add`** —— ⚠️ `tb_all.ps1` 把 `rtl/` 与 `tb/` 下**所有**文件编进**每一个** tb，而脚本把"回归非零退出"当成 `CAUGHT` ⇒ ⭐ **中途新增/弄坏任何文件，都可能让剩余变异体【全部假 CAUGHT】**（⭐ 同族 `K-105`）。<br>📌 **已同步更正**：脚本头部原来写着"28 benches / all 37 / ~109 s"（⚠️ **已过时**：现在是 **36 个 tb / 76 个变异体**），✅ 已改为实测口径 + 本节纪律。 |
| **K-116** | ⚠️ **两个 `.ps1` 里有中文注释且【无 BOM】—— 属 `U61`/`K-38` 隐患（⭐ 实测当前可解析，暂不修）**（2026-09-23 顺带排查发现） | **事实（实测）**：<br>· ⚠️ `bringup/mutation_test.ps1` —— **5 行**非 ASCII（302~306 行，⭐ 中文注释），**无 BOM**；<br>· ⚠️ `sim/gowin_build.ps1` —— **1 行**非 ASCII（第 36 行，⭐ 一个 `⭐` 符号），**无 BOM**；<br>· ✅ 对照：`sim/tb_all.ps1` 有 **1670 个**非 ASCII **但有 BOM** ⇒ ⭐ **安全**（PS 5.1 按 BOM 正确解码）。<br>**为什么现在不修**：⭐ **两个脚本当前都能被 `PSParser` 正常解析**（0 错误），且 ⚠️ **非 ASCII 全部落在 `#` 注释里** —— ⭐ `#` 是单字节 `0x23`，**不会被 GBK 解码吞掉** ⇒ ⚠️ **实际触发风险低**；⭐ 而**此刻变异测试正在跑**，⚠️ 改脚本有额外风险。 | 工具链 | ⚠️ 潜在：**PS 5.1 按 GBK 解无 BOM 的 UTF-8 ⇒ 中文注释可能改变语法** | 🟡 **已知隐患，⛔ 暂不修（2026-09-23）**：<br>⭐ **依据**：当前**解析通过** + 非 ASCII **仅在注释内**（`#` 不会被吞）。<br>⭐⭐ **触发条件（⚠️ 何时必须修）**：⭐ **一旦要在这两个脚本里加新的中文注释/字符串**，⇒ ⭐ **要么保持纯 ASCII、要么给文件加 BOM**（⭐ `tb_all.ps1` 的 BOM 做法是正确范例）。<br>📌 **纪律**：⭐ **新建/修改 `.ps1` 时，UTF-8 无 BOM 只允许纯 ASCII**（⚠️ 本会话已踩过一次：我加的中文注释引入 **108 个非 ASCII**，✅ **已全部改回 ASCII**）。<br>🔴 **注意**：`.ps1` 与 `.md` **规则相反** —— ⭐ **`.md` 要求无 BOM**（`C17`），⭐ **`.ps1` 要么纯 ASCII、要么带 BOM**。 |
| **K-117** | ⚠️ **`tools/check_evidence.py` 把「编译干净 ⇒ `*.compile.log` 为空」误判成「证据为空」⇒ 守卫永久拒绝**（2026-09-23 变异收尾时发现） | **现象**：全量变异跑完（**75/75 caught、0 LEAK、0 SKIP、exit 0**）+ 干净回归 **36/36** 之后，`check_evidence.py` **仍然 `REFUSING to commit evidence`**，列出 **34 个 `*.compile.log` 为空**。<br>**根因**：⭐ `sim/tb_all.ps1:101` 把 `iverilog` 的 stdout+stderr 整体写进 `<tb>.compile.log`，而 ⭐ **iverilog 在【编译干净】时【什么都不打印】** ⇒ 编译成功 ⇒ **日志合法地为 0 字节**。⚠️ 但判据是"tracked 证据文件为空即拒绝"（`ALLOW_EMPTY = set()`，第 44 行）⇒ 🔴 **"编译通过"这一最常见情况被判成"证据缺失"**。<br>**实测证据**：单独编译 `tb_adc_farm` ⇒ **退出码 0、输出 0 字节**；⭐ **36 个 tb 的运行日志全部有 `PASS`、无一为空**（42 个含结论、0 个空、0 个 `FAIL:`）⇒ ⭐ **真实证据完好**。<br>⚠️ **附带发现**：34 个空文件里 **9 个在 HEAD 里是 576 字节** —— ⭐ 内容是一段 **`timescale` 继承警告的 `NativeCommandError` 文本**（`evt_uart_rx.v` 的 `module evt_uart_rx` 声明处）。⚠️ 但该文件**现在第 1 行就是 `` `timescale 1ns/1ps ``**，⭐ 且提交 `a3f15b0`（"回归 36/36 + **timescale 修正**"）⇒ ⭐ **那 576 字节是修正【之前】的陈旧产物**，被这次干净回归**正确地**刷成 0 字节。 | 验证工具 | ⚠️ **"证据可否提交"这个守卫本身**（⭐ 它会**永远拒绝** ⇒ 守卫失去意义） | ✅ **已修（2026-09-23）**：<br>⭐ **修法**：在 `tools/check_evidence.py` 增加 **`EMPTY_OK_SUFFIXES = (".compile.log",)`**，⭐ **空编译日志被跳过**。<br>⚠️ **刻意【不用】建议①的 `ALLOW_EMPTY`** —— 那会**整体跳过**空检查（含将来"本该有内容却空"的 compile log）；⭐ **后缀豁免更窄、更安全**。<br>⭐ **修法依据（实测，⛔ 不是猜）**：40 个 `*.compile.log` 里 **38 空 / 2 非空**，⭐ **而那 2 个非空装的都是【警告】**（dangling port / 位宽不匹配）⇒ ⭐ **"空 = 干净"成立**。<br>⭐ **双向验证**：① 正常情况 ⇒ `OK: evidence looks clean`（**exit 0**）；② ⭐ **故意放一个非 `compile.log` 的空文件** ⇒ 仍报 `EMPTY` 且 **exit 1** ⇒ ⭐ **守卫本职（防空/防污染）完好**，⛔ 没有为了消警告而废掉它。<br>📌 **纪律（保留）**：⭐ **"守卫报警"要先分清是【被测有问题】还是【守卫判据有问题】** —— ⚠️ 若盲信守卫，会去"找不存在的证据"（同 `K-110`：判据本身算错，连续误判三次）。 |
| **K-118** | 🔴⭐ **两条会话共用同一个工作区 ⇒ 【当前分支会被对方切走】⇒ 提交静默落到别人的分支上**（2026-09-23 实测**连发两次**） | **现象（连发两次）**：<br>· 第 1 次：`7bed778`（我的变异结果）落到 **`feat/s3-ble`** 上；<br>· ⭐ 用 `cherry-pick` 搬回 `main` 后，**第 2 次又发生**：`ba61ffc`（我的 PA_EN 修复）**再次落到 `feat/s3-ble`**。<br>**根因（`git reflog` 实证）**：<br>```
6f69271 HEAD@{2}: checkout: moving from main to feat/s3-ble   ← 另一条会话切的
bec3f5b HEAD@{1}: commit: 串口屏电平确认…                      ← 另一条会话的提交
```<br>⭐ **同一个工作区里跑着两条会话**（FPGA 线 + ESP32 线）⇒ ⚠️ **`git checkout` 是【进程外共享状态】**，对方一切分支，**我这边的工作目录就跟着变**。⚠️ 而 `git commit` **零报错** ⇒ 🔴 **归属错了却看不出来**。 | 协作 / 版本控制 | 🔴 **提交归属**；⚠️ 连带影响 **压提交 + push**（会把两条线混进同一条历史） | 🔴 **已定位，⚠️ 已两次手工修复，⛔ 尚无自动防护**：<br>⭐ **两次修法（已验证有效）**：`git checkout main` → `git cherry-pick <我的提交>` → `git branch -f <对方分支> <它原来的提交>`（⚠️ 前提：先 `git show --stat` 确认该提交**只含自己的文件**）。<br>⭐⭐ **纪律（⛔ 违反必再犯）**：<br>① **每次 `git add`/`commit` 之前【当场】查分支** —— `git branch --show-current`，⛔ **不靠记忆、不靠上一次查的结果**；<br>② **`commit` 之后立刻看 `git status -sb`** —— ⭐ 分支名 + **有无 upstream** 一起暴露；<br>③ **提交用显式文件路径**（⛔ 不用 `-A`/`.`）⇒ ⭐ **这样落错了也能干净 `cherry-pick` 搬回**（⭐ 两次都是靠这条救回来的）；<br>④ ⚠️ **长任务（回归/变异）跑完后要【重新查分支】** —— ⚠️ 它跑了十几分钟，期间对方随时可能切走。 |
| **K-119** | 🔴🔴 **在变异测试【运行期间】动 `rtl/` ⇒ ⚠️ 连"我自己的手工备份"都会被污染 ⇒ 差点把变异体写进真 RTL**（2026-09-23 实测，⭐ **本人失误**，`K-115` 的**新一层危害**） | **经过（实测时间线）**：<br>· **09:15** 变异测试为 **M59** 备份 `uart_rx.v`，并**把 `rx_done_o <= 1'b1;` 改成 `1'b0`**（M59 的变异）；<br>· **09:26** ⚠️ **我为"保护自己的改动"把 `uart_rx.v` 复制到 `build/baud_backup_...`** ⇒ 🔴 **此时磁盘上是【带变异的版本】⇒ 我的"备份"里带着 M59 的缺陷**；<br>· **09:35** 变异跑完，从**它自己的**备份还原 ⇒ 磁盘回到正确状态；<br>· **09:39** 🔴 **我从【自己的污染备份】"恢复"** ⇒ ⭐ **把 M59 的缺陷又写回了真 RTL**。<br>**后果**：`uart_rx` 的完成脉冲恒为 0 ⇒ **一个字节都收不到**（tb 报 `byte[0] = xx`）。⚠️ **若未经验证就提交，这就是一个真缺陷进 RTL**。<br>**怎么发现的（⭐ 靠"改完立刻验证"）**：① 改完跑两个 tb ⇒ **都 FAIL**；② 用**干净 HEAD** 对照 ⇒ **HEAD PASS** ⇒ 证明是**我引入的**；③ **隔离实验**（HEAD 的 RTL + 我的 tb）⇒ **PASS** ⇒ 锁定在 **RTL**；④ **去掉注释行逐行对比** ⇒ 精确到那一行。<br>**修法**：从 `git show HEAD:rtl/w3c/uart_rx.v` 取回**正确逻辑行**，保留我的注释改动 ⇒ ⭐ **核验"去注释后与 HEAD 只差 `BAUD_DIV` 一行"**（即预期的唯一改动）。 | RTL + 验证流程 | 🔴 **代码正确性**（⭐ 会静默写进缺陷）；⚠️ 且**污染的是"用来保护代码的备份"本身** | ✅ **已修并验证（2026-09-23）**：回归 **36/36**、`tb_uart_rx` PASS（`BAUD_DIV=50 => 1000000 bps`）、`tb_evt_uart_rx` PASS；⭐ `evt_uart_rx.v` 经检查**未受污染**。<br>⭐⭐ **教训（新增，比 `K-115` 更深一层）**：<br>① 🔴 **`K-115` 原来只写了"会假 CAUGHT / 假 LEAK"** —— ⚠️ **实际危害更大：手工备份会被污染，从而把变异体"洗"进真代码**；<br>② 🔴🔴 **`build/` 下的"手工备份"【不可信】** —— ⭐ **它可能在不知不觉间捕获到中间态**；⭐ **唯一可信的基准是 `git`**（`git show HEAD:<file>` / `git stash`）；<br>③ ⭐⭐ **"改完立刻跑 tb"是唯一能兜住这类错误的手段** —— ⚠️ 本次若省略这一步，缺陷会**直接进提交**；<br>④ ⭐ **隔离实验定责**：`HEAD-RTL + 我的 tb` ⇒ 若 PASS，则问题**必在 RTL**（反之在 tb）—— ⭐ 这是**二分定责**的标准动作，⛔ 不要靠猜。 |
| **K-120** | 🔴⭐ **写【变异体】本身有三个静默陷阱，会让整个 catalogue 解析失败或失去保护**（2026-09-23，⭐ **三个都是我踩出来的**） | **① PowerShell 数组字面量的【末条不能带逗号**】—— ⚠️ 否则报 `Missing expression after ','`，⚠️ 而报错指向的行号是**别处**（真实损坏点在数组结尾）；⭐ 原文件的末条 `M44` **故意不带逗号**，⛔ 追加时若给最后一条加逗号就废掉整个数组。<br>**② 锚点（`find`）里⛔ 不能嵌非 ASCII** —— ⚠️ 我一度把 RTL 的 `// \u2b50 \u94b3\u4f4d...` 中文注释抄进锚点 ⇒ ① 文件非 ASCII 字节从 287 涨到 311（`K-116` 隐患）② PowerShell 直接解析失败。⭐ 锚点必须**纯 ASCII 且唯一**。<br>**③ 插入行的行尾必须与宿主一致** —— ⚠️ `mutation_test.ps1` 是 **LF-only**，我按 `\r\n` 拼接 ⇒ 🔴 **CRLF 混入后解析失败**，⚠️ 而报错信息（"Missing expression after ,"）**完全看不出是行尾问题**。<br>⭐⭐ **根因共性**：⚠️ **三个陷阱的报错都指向"数据行"，而真因在"数组结构 / 编码 / 行尾"** ⇒ ⭐ **靠读报错猜字符，全部猜错**（我为此浪费了 8 轮）。<br>✅ **正解 = 机械二分**：⭐ **把插入块删掉 ⇒ 若语法恢复，则问题必在插入内容**；⭐ **再逐行加回，第一个失败的行就是元凶**（⭐ 我最后就是这么定位的，一次命中）。<br>✅ **已固化为守卫**：`build/_add_w3a_mutants.py` 在写入前自动检查 **① 锚点恰好出现一次 ② find/repl 纯 ASCII ③ 末条不加逗号**；⭐ 并且**写完后必须跑 `Parser::ParseFile` 全文件语法检查**（⛔ 不要凭"我写得对"）。 |
| **K-121** | ⚠️ **`git push` 报 `Permission denied (publickey)` —— 根因是 `ssh.exe` 不在 PATH**（2026-09-23，⭐ 推提交时撞到） | **现象**：⭐ `git push origin main` ⇒ 🔴 `git@github.com: Permission denied (publickey).` + `fatal: Could not read from remote repository.`<br>⚠️ **极易误判成**"key 失效 / 权限被改 / 远端删库"，⭐ **而实际都不是**。<br>**根因**：🔴 **`C:\Windows\System32\OpenSSH` 不在 PATH 里**（⭐ 本机 PATH 只有 `C:\Program Files\Git\cmd` 与 `...\Git\bin\bash.exe`）⇒ ⭐ git 拉起的 ssh **解析不到可执行文件** ⇒ 被 SSH 报成认证失败（⚠️ 错误信息误导性极强）。<br>**⭐ 判别法（3 步，⛔ 别瞎改 key）**：① `ssh-add -l` —— ⚠️ 若"命令找不到"就**已指向 PATH 问题**；② ⭐ **用【完整路径】手测**：`& "C:\Windows\System32\OpenSSH\ssh.exe" -T git@github.com` ⇒ ⭐ 若回 `Hi <user>! You've successfully authenticated` ⇒ ✅ **key 完全正常，就是 PATH 的事**；③ `Get-ChildItem $env:USERPROFILE\.ssh` 确认 key 文件在（⭐ 本次 `id_ed25519` 在）。<br>**修法**：⭐ **把 `C:\Windows\System32\OpenSSH` 加进【User PATH】**（⚠️ 幂等追加）：<br>`$u=[Environment]::GetEnvironmentVariable('PATH','User'); if(($u -split ';') -notcontains 'C:\Windows\System32\OpenSSH'){[Environment]::SetEnvironmentVariable('PATH', $u.TrimEnd(';')+';C:\Windows\System32\OpenSSH', 'User')}`<br>**⚠️ 副作用**：⭐ **改 PATH 后【已在运行的进程】看不到** ⇒ **要重启 DSH Desktop** 才全局生效；⭐ 重启前可用 **`$env:GIT_SSH="C:\Windows\System32\OpenSSH\ssh.exe"`** 应急（⭐ 本次就是这么推成功的）。<br>📌 **与 `K-116`/`C17` 的区别**：那两条讲**编码/BOM**，⭐ 本条讲**可执行文件解析** —— ⚠️ 但共性都是"**表面报错指向 A，真因在 B**"。 | 环境 / git | ⭐ 任何 `git push`（⭐ 复发概率 100%，直到 PATH 修好） | ✅ **已修（2026-09-23）**：⭐ 已加进 User PATH 并**实测生效**（`Get-Command ssh` 可解析、`ssh -T` 回认证成功）。⚠️ **DSH 重启前仍建议用 `$env:GIT_SSH` 兜底**。 |
| **K-122** | 🔴🔴 **`-Changed` 在改动【共享/集成文件】时不会触发 FULL ⇒ ⚠️ 给出"通过"的假结论**（2026-09-24 实测，⭐ **脚本头部已承诺、代码里没实现**） | **现象**：⭐ `mutation_test.ps1` 头部第 39~41 行**明确写了**：`* touched a SHARED file ... FULL run, always (sim/tb_all.ps1, tb/models/*, tb/checkers/*, sim/evidence/*)` 与 `* touched rtl/top.v ... FULL run (it is the integration point)`。<br>🔴 **而代码里【什么都没实现】** —— 全文 grep `FULL` **只有 2 处，都是显示字符串**（第 439/443 行）。<br>**🔴 后果（⚠️ 这才是危险的）**：⭐ 实测匹配（用脚本【真】逻辑跑过）：<br>· 改 `rtl/w3a/calib_span.v` ⇒ ⭐ 只选 `calib_span` 的 ✅ **正确**<br>· 🔴 **改 `rtl/top.v`** ⇒ ⚠️ **只选 `top.v` 自己的那 2~3 个** ⇒ ⭐ **全 caught ⇒ 脚本报"全部通过"**<br>· 🔴 **改 `sim/tb_all.ps1`** ⇒ **1 个都选不中** ⇒ ⚠️ 走 0 匹配（⭐ 这条**已被挡住**，见下）<br>· 🔴 **改 `tb/models/*`** ⇒ ⚠️ 只有用到它的那几个<br>⇒ 🔴 **而 `top.v` 的改动在语义上等价于"全量改动"**（⭐ 它是集成点：例化/参数/连接的改动 ⚠️ **会影响那个模块的全部行为**，⭐ 甚至让一批变异体从"抓得住"变成"抓不住"）<br>⇒ 🔴 **真实情况：某个 LEAK 完全没被发现，而报告是"通过"**。<br>📌 **这是 `K-97`/`C29` 那一族 —— "没有验证"被当成"验证通过"**，⚠️ 只不过**换了件衣服**：⭐ 不是"0 个"（那个**已被挡住**：脚本第 446~452 行有明确注释 + `exit 5`），🔴 而是 **"选少了但非 0"（⭐ 没有任何守卫）**。<br>**⭐ 修法（三处，都很小）**：① ⭐ **加"强制 FULL"判定** —— changed 命中 `rtl/top.v` / `sim/tb_all.ps1` / `tb/models/` / `tb/checkers/` ⇒ **走 `$allMutations`（⭐ 筛选【之前】的完整列表）**；② ⭐ **打印"是哪几个文件触发的"**（⭐ `K-106` 纪律：⛔ 不许静默改变行为）；③ ⚠️ 若 selected < 总数 30% ⇒ **额外提示"只验了一小部分，涉共享设施请重跑 FULL"**<br>📌 详细方案：`files/20-代码/变异测试-Changed机制分析与改进-20260924.md` | 工具 / 变异测试 | 🔴 **任何用 `-Changed` 的日常开发**（⭐ 涉及 `top.v` 时**必然**给出假结论） | 🟡 **方案已写、⛔ 代码未改**（⭐ 改脚本要等变异测试不跑的窗口） |
| **K-123** | 🔴⭐ **变异测试【不能与另一个 worktree 的 git 写操作并行】** —— ⚠️ `K-119` 的范围**不够宽**（2026-09-24 实测） | **事实（⭐ `git worktree list` 实测）**：`FPGA2026 [main]` 与 `FPGA2026-esp32 [feat/s3-ble]` ⭐ **两个 worktree【共享同一个 `.git`】**（⭐ 在 `.git` 的 `worktrees` 子目录下各有一份 HEAD）。<br>**🔴 风险**：⭐ 变异测试**改 `rtl/` 并靠 `.bak` 还原**（⛔ **不经过 git**）；⚠️ 而**另一个 worktree 的 `merge`/`rebase`/`checkout`/`reset`** 可能：<br>· 🔴 **覆盖被变异的那个文件** ⇒ ⚠️ 变异测试的结论**作废**<br>· 🔴 或反过来：**merge 拿到被变异的源码** ⇒ ⚠️ **把变异提交进去**<br>**📌 实测现场（2026-09-24 凌晨）**：⭐ ESP32 那边**正在 merge**（`MERGE_HEAD` 存在、**100 文件已暂存**、⚠️ 且暂存内容**含 `bringup/mutation_test.ps1` 自己**）⇒ ⭐ **立即 `job_kill` 停掉变异测试**（⭐ 判断正确）。<br>⚠️ **但强杀有代价**：🔴 **`rtl/clk_gen.v` 残留了 M01 变异**（`CLK_PER_SAMPLE - 1` 被改成 `- 2`）⇒ ⭐ **靠 `build/mutation/backup/clk_gen.v.M01.bak` + 字节级比对才手工还原**（⭐ 幸好脚本留了 `.bak`）。<br>⇒ ⭐⭐ **再次印证脚本头部那条硬前提**：🔴 **跑全量前【必须先 commit】**（⚠️ 否则分不清"残留变异"和"我自己的改动"）。<br>**⭐ 建议补进 `K-119`**：⛔ **不与【另一个 worktree 的任何 git 写操作】并行**。 | 流程 / 多线并行 | 🔴 **变异测试 × ESP32 线并行开发**（⭐ 本项目长期存在） | 🟡 **纪律已明确，⚠️ 待写进 `AGENTS.md` 二节** |
| **K-125** | 🔴⭐ **`K-120` 第②条陷阱的【真实复现】：一个中文锚点让 `M85` 静默失去保护**（2026-09-24 全量变异测试跑出来） | **现象**：⭐ 全量 90 个变异体跑完 ⇒ 🔴 `M85` 报 `SKIP -- anchor text not found in rtl\w3c\master_mix.v`。<br>⚠️ **第一反应是"RTL 改过、锚点过时"**（⭐ 就像同批的 `M40`）—— 🔴 **但实测【不是】**：<br>⭐ 手动验证 `ReadAllText(master_mix.v).Contains(find)` ⇒ ✅ **True**（⭐ 锚点明明在文件里！）<br>🔴 **真因**：⭐ **锚点尾部带了中文注释**（`// 复位静音（安全态）`，⭐ **27 个非 ASCII 字节**）⇒<br>　· `mutation_test.ps1` 是 **无 BOM 的 UTF-8**<br>　· **PowerShell 5.1 按 GBK 解码无 BOM 文本**（`K-38`）⇒ ⭐ **脚本里的中文变成乱码 A**<br>　· 而 `rtl/` 源码用 `ReadAllText`（默认 UTF-8）读 ⇒ **正常中文 B**<br>　· 🔴 **A != B ⇒ `Contains` 为假 ⇒ SKIP**<br>⇒ 🔴 **一个变异体【彻底失去保护】，而它的 `why` 还写着 "must be caught"**。<br>**⭐ 判别法（⭐ 关键）**：⭐ **不要只看"锚点过时"** —— ⭐ 先做一步机械检查：<br>`$b=[Text.Encoding]::UTF8.GetBytes($find); ($b \| ? {$_ -gt 127}).Count`<br>⭐ **结果 > 0 ⇒ 几乎必然是本条**。<br>**✅ 修法**：⭐ **锚点只留纯 ASCII 的代码部分**（⭐ 尾部注释一律删掉）：<br>`find = "gain_r <= {GAIN_W{1'b0}};"`（⭐ 实测在文件里**唯一**，⭐ 够用）。<br>**⭐ 已固化为纪律**：⭐ **全脚本 91 个变异体的 `find`/`repl` 现在【全部纯 ASCII】**（⭐ 实测 0 个违规）；<br>⚠️ 脚本里残留的 **287 个非 ASCII 字节【只在注释行】**（⭐ 无害，它们不参与匹配）。<br>📌 **与 `M40` 的区别（⭐ 同批但不同因）**：⭐ `M40` 是**真·锚点过时**（⭐ 变量名 `mx_*` 改名成 `mm_*`）<br>⇒ ⭐⭐ **两个 SKIP 长得一模一样，根因完全不同** ⇒ ⚠️ **必须逐个查，⛔ 不能一起下结论**。 | 工具 / 变异测试 | 🔴 **任何含非 ASCII 注释的锚点**（⭐ 一旦 RTL 那行改动就会暴露） | ✅ **已修（2026-09-24）**：`M40` 改锚点为 `mm_valid` 那条；`M85` 去掉尾部中文注释。⭐ **两个都单跑验证过 `caught`** |
| **K-124** | 🔴🔴 **`param_extract` 的力度阈值【超出量程】⇒ 力度功能静默失效**（2026-09-24 发现，⭐ **`K-87`/`K-106` 同族**） | **事实（⭐ 全部实测）**：`rtl/w3a/param_extract.v` 的 `VEL_T1`/`VEL_T2` 的默认值是 `VEL_T1 = 12'h200`（512）、`VEL_T2 = 12'h600`（**1536**）；⭐ 而 `:218` 的用法是 **`if (pos_i[...] >= VEL_T2)`** ⇒ ⭐ **两者是【绝对码】比较**（⛔ 不是比例）。<br>🔴 **后果**：⭐ 现状行程（只 `tare`）= **0..744** ⇒ **`VEL_T2 = 1536`（= 行程的 206%）永远达不到** ⇒ `t1_seen` 会置起、但 `was_above_t2` **永远为假** ⇒ **`Δt` 永远算不出来** ⇒ 🔴 **所有音同一个力度**（⭐ 力度功能完全失效）。<br>⚠️ **自检查不出来**：`PARAM_OK` 只查 `VEL_T2 > VEL_T1` ⇒ `1536 > 512` ✅ **通过** ⇒ 🔴 **缺陷静默通过**。<br>🔴 **为什么 tb 全过**：`tb_param_extract.sv:32-33` 自带 `T1=0x200`/`T2=0x600`（⭐ 数值同默认值），⚠️ **但 tb 喂的 `pos` 是 tb 自己造的**（⭐ 可超过 744）⇒ ⭐ **从没测过"真板行程下能不能达到 `T2`"**。<br>📌 **这正是经验库 `87 号` 的镜像**：*"16 项判据全过、变异体全抓，模块里却还藏着真缺陷"* —— 根因是 ⭐ **判据围绕 tb 自己的配置设计，⛔ 没覆盖 `top.v` 的实际配置**。<br>**✅ 修法**：⭐ **在 `top.v` 例化时显式传参**（⭐ 与 `TRIG_TH`/`REL_TH` 同一模式）：<br>· 只 `tare`（行程 744）：`VEL_T1 = 0x174`(372, 50%) · `VEL_T2 = 0x253`(595, 80%)<br>· `span` 后（4094）：`VEL_T1 = 0x7FF`(2047) · `VEL_T2 = 0xCCB`(3275)<br>🔴 **约束**：`REL_TH < TRIG_TH < VEL_T1 < VEL_T2 <= 行程`（⭐ 四者共享同一个 `pos` 空间 ⇒ ⚠️ 必须成套改）<br>📌 详细推导：`files/20-代码/span标定后阈值调整-20260924.md` §四 | RTL / 阈值 | 🔴 **力度（velocity）功能** —— ⭐ 当前的**交付配置下完全失效** | ✅ **已修（`top.v` 的 `.POS_FULL(TRAVEL_TARE)` + `param_extract.v` 的 `VEL_T1_EFF`/`VEL_T2_EFF` 与 `PARAM_OK`）** —— ⭐ 原计划"上板验通出声之后再改"已执行 ✅ |
| **K-126** | 🔴🔴⭐ **回包被 `uart_tx` 静默丢弃：`need_press` 只高 1 拍，而发 1 字节要 20 µs ⇒ 轴号提示 100% 必丢**（2026-09-24 上板实测，⭐ **`K-106`/`K-87` 同族：路径能失败却不可见**） | **现象（⭐ 实测）**：⭐ 串口发 `'S'` ⇒ 只收回 `s`（受理），🔴 **之后再也没有任何轴号提示**；⭐ 而发 `'T'` 能正确收回 `t` … `T`。<br>**根因（⭐ 时序实测）**：· `calib_span.v` 的 `S_PROMPT` **只执行一次就转 `S_SETTLE`** ⇒ `need_press_o` 只高 **1 拍 = 20 ns**（⭐ `cur_axis_o` 同样只稳 1 拍）；· 而 `top.v` 的 `rep_req` 由 `ev_need = sp_need_press & ~sp_need_r` 驱动 ⇒ ⭐ **也是 1 拍脉冲**；· 🔴 但 `uart_tx` 发一个字节要 **10 bit ÷ 500 kbps = 20 µs**，⚠️ 且它**忙时直接忽略新请求**（⭐ `top.v` 注释自己承认"第二个会被丢弃"）⇒ 🔴 **20 ns 的请求撞上正在发 `'s'` 的 20 µs ⇒ 必然被丢，⛔ 不会重发**。<br>**⚠️ 影响**：⭐ 标定**仍能走完**（⭐ 按 `cur_axis` 顺序盲按即可，⭐ `.`/`!` 回包不撞车），🔴 但**操作者不知道该按哪一轴** ⇒ ⚠️ 16 轴全靠盲按。<br>**✅ 修法（⭐ 已评估，⭐ 已实施 2026-09-30）**：① ⭐⭐ **在 `top.v` 加一个回包 FIFO**（⭐ 深度 4~8 × 8 bit）⇒ ⭐ 占用 `<0.5%`（⭐ 64 FF / 32 LUT，当前 LUT 14252 / FF 8778）· ⭐ 时序余量 13.8% ⇒ ⚠️ 预计仅降 0.2~0.5 MHz ⇒ ✅ **可接受**；② ⚠️ 或把 `need_press_o` 改成**保持到轴完成**（⭐ 改动小，⚠️ 但 `rep_req` 会反复触发）。<br>**📌 预估工时**：⭐ 写 FIFO 10 min + tb 判据 5 min + 回归 5 min + PnR 10 min = **~30 min** | RTL（top.v / calib_span.v） | ✅ **已修**（⭐ 2026-09-30 回填；⭐ 原标 **🔴 未修** —— 原记录：⭐ 用户拍板：**先做 DAC 出声，⭐ 稍后修**）<br>⭐ 已核实（2026-09-30 夜）：`top.v` 已新增回传发送队列 `uart_tx_fifo`（⭐ 深度 8），其注释原文写明「**2026-09-24 新增，修 `K-126`**」，且 `.push_i (tx_req)` 那行注释写明「**单拍也可（当拍即入队）**」⇒ 20 ns 的请求不再撞上正在发字节的 `uart_tx` 被静默丢弃 —— 见 `rtl/top.v` 的 `u_tx_fifo` |
| **K-127** | 🔴⭐ **`calib_span` 的 `raw_i` 只接了【片 0】⇒ 轴 8~15 会拿片 0 的值做标定**（2026-09-24 上板期间查"轴位"时发现） | **事实（⭐ 代码级）**：<br>· `top.v` 里 `u_calib_span` 的 `.raw_i (af0_pol)` —— 🔴 **恒为片 0**（`af0_pol = axis_polarity(af_data[0*12 +: 12])`）；<br>· 而 `AXIS_TOTAL = 16`（⭐ 2 片 × 8 通道）⇒ ⭐ 轴映射是 `轴 = 片 × 8 + 通道`；<br>· `calib_span` 用 `sample_ch_i == cur_axis[2:0]` 判"本轴"（⭐ 行 321/353/438），`calib_span.v` 的 `cal_ch_o` 又 `cal_ch_o <= cur_axis[2:0]`。<br>**🔴 后果**：⭐ 轴 8~15（⭐ 片 1）**记的是片 0 的读数** ⇒ 标定结果错位；⚠️ 而且**没有任何报错**（⭐ `K-106` 同族：路径能错却不可见）。<br>**⚠️ 影响面**：⭐ 当前【左手板只有 1 片 `U1` 是实的】（⭐ 另一片是空的）⇒ 轴 0~7 正确、⭐ 轴 8~15 本来也没信号 ⇒ ⚠️ **现在不影响回放**，⛔ 但**将来接第二片就会错**。<br>**✅ 修法（⭐ 已实施 2026-09-30）**：① `calib_span` 新增一个"当前片"输入（如 `cur_plane_i`），`raw_i` 改成按片选 `af0_pol`/`af1_pol`；② ⚠️ 或把 `AXIS_TOTAL` 按实际片数参数化（⭐ 现在 2 片但只接 1 片）。<br>📌 **判据**：⭐ 修完必须有一条 tb 判据守"轴 8 用的是片 1 的值"。 | RTL（`top.v` / `calib_span.v`） | ✅ **已修**（⭐ 2026-09-30 回填；⭐ 原标 **⬜ 待办** —— 原记录：⭐ 用户拍板：先记录）<br>⭐ 已核实（2026-09-30 夜）：`top.v` 已新增按片选择 `sp_raw_sel = sp_cur_axis[3] ? af1_pol : af0_pol`，并已接到 `u_calib_span` 的 `.raw_i (sp_raw_sel)`（⭐ 引入提交 `e1d36bf`）⇒ 轴 8~15 用的是片 1 的值，⛔ 不再是恒为片 0 —— 见 `rtl/top.v` 的 `sp_raw_sel` |
| **K-128** | 🔴🔴⭐ **全代码库把"转换耗时"当成"帧周期"：注释里的 196 µs 已作废，实测是 500 µs ⇒ 所有"按帧数换算毫秒"的常量都小了 2.55 倍**（2026-09-25 排查 span 卡点时顺带查出） | **⭐ 证据 A（仿真实测，⭐ 权威）**：`sim/evidence/tb_adc_farm.log` 判据行 —— ⭐ `PASS: 2 frames, 16 sample_valid, 24 samples total, frame period=500000 ns` ⇒ ⭐ **帧周期 = 500 µs**。<br>**⭐ 证据 B（逐拍算术，⭐ 独立复算，⭐ 与 A 吻合）**：`HALF_DIV = 50e6/(2×1e6) = 25 拍` ⇒ 每位 50 拍 ⇒ 24 位 = 1200 拍 + `STATE_FINISH` 的 25 拍 = **单通道 1225 拍 = 24.5 µs**；⭐ 8 通道【顺序】= **9800 拍 = 196 µs**（⚠️ 这只是**转换耗时**）；🔴 但 `mcp3208_scanner.sv` 的 `FRAME_PERIOD = CLK_HZ/CHANNEL_RATE_HZ = 50e6/2000 = 25000 拍 = 500 µs`，⚠️ 且 `9800 < 25000` ⇒ ⭐ **转换先完，然后 `STATE_WAIT_PERIOD` 空等到 25000 拍** ⇒ 🔴 **真帧周期 = 500 µs（⛔ 不是 196 µs）**。<br>**🔴 根因**：`K-79` 改过帧周期口径，⭐ **但 `adc_farm.sv` 的注释没跟着改** —— 🔴 **同一个文件第 25 行写"0.5 ms"（✅ 对）、第 47 行写"196 µs"（🔴 错），自相矛盾**；⚠️ **而下游抄的是那条错的**。<br>**🔴 被污染的常量（⭐ 逐个核过）**：① `calib_span.v` 的 `STABLE_NEED` `STABLE_NEED=24` 注释称"4.7 ms"实际 **12 ms**；② 🔴 `top.v` 的 `REFRACT_N` `REFRACT_N=150` 注释称"30 ms"实际 **75 ms** ⇒ ⚠️ **触键不应期是期望的 2.55 倍 ⇒ 快速连击会被吞（⭐ 唯一有【实际功能后果】的一条）**；③ `event_extract.v` 的三处 `K-128` 帧周期注释（⭐ 含"一帧 9800 拍"⇒ 实为 **25000 拍**）；④ `calib_span.v` 多处 `@196 µs/帧`。<br>**✅ 修法（⭐ 已实施 2026-09-25）**：⭐ **改注释 + 把 `REFRACT_N` 150 → 60**（⭐ 保持"约 30 ms"的设计意图：30 ms ÷ 500 µs = 60 帧）⇒ ⭐ 注释与行为**同时正确**。🔴 **⛔ 不改 `CHANNEL_RATE_HZ`**（⚠️ 改成 5094 会连带影响 `VOTE_N`/`STABLE_NEED`/`debounce` 全部时序常量 ⇒ 需重跑全量回归 + 变异测试，⛔ 不划算；⭐ 且"5094 Hz"那句本身就是旧口径残留）。<br>**📌 教训**：⭐ **"实测"两个字会被抄进注释，然后被当成事实反复引用** —— 🔴 而**注释里的数字没有回归保护**（⭐ 代码改了它不会红）。⭐ **防复发**：把帧周期做成【被 tb 断言的常量】而不是注释里的字符串（⭐ `tb_adc_farm` 已在断言 `frame period=500000 ns` ⇒ ⚠️ 建议让它**从 RTL 参数算期望值**，这样口径再变就会红）。⚠️ **更普遍的教训**：⭐ **"转换耗时" ≠ "帧周期"** —— 前者是器件物理极限，后者是设计选择的节拍；🔴 混为一谈就会得出"5094 Hz/通道"这种**纸面达标、实际 2000 Hz** 的结论。 | RTL 注释（`adc_farm.sv` / `calib_span.v` / `event_extract.v` / `top.v`） | ✅ **已修**（⭐ 2026-09-25：注释全改 + `REFRACT_N` 150→60；⭐ 单跑 tb 三条全过，全量回归待确认） |
| **K-129** | 🔴🔴⭐ **缩短仿真超时会【改变被测行为】⇒ 我用小超时跑 tb 得出了完全错误的结论（`calib_span` 其实是对的）**（2026-09-25 排查 span 卡点时自己踩到） | **⭐ 事情经过**：⭐ 为定位 `'S'` 反复回 `0!`，我写了 3 支 tb 测 `calib_span`。<br>· ⭐ 第 1 支：`WAIT_TIMEOUT_CLK = 200` 拍 ⇒ 🔴 报"零抖动也必拒 ⇒ 逻辑有缺陷"<br>· ⭐ 第 2 支：`WAIT_TIMEOUT_CLK = 2000` 拍 ⇒ 🔴 报"`stable_cnt` 攒不到 8"<br>· ⭐ 第 3 支：`WAIT_TIMEOUT_CLK = 640000` 拍（⭐ **与上板同比例**）⇒ ✅ **span=16 / reject=0**<br>🔴 **真因**：⭐ 上板真值 `WAIT_TIMEOUT_CLK = 50_000_000` 拍 = **1 秒**，⭐ 而帧率 **2000 Hz** ⇒ ⭐ **1 秒 = 2000 帧**。⚠️ 我把超时缩到 200 拍 ⇒ **只够 1.25 帧** ⇒ 🔴 **人为制造了"必超时"**。<br>**📌 判据（⭐ 机械可查）**：⭐ **保持【超时 ÷ 帧周期】这个比值不变**，⛔ 不是随便缩小绝对值。⭐ 本 tb 的做法：⭐ 帧压到 40 拍/通道 ⇒ 超时 = 40×8×2000 = 640000 拍（⭐ 比值仍是 2000 帧）。<br>**🔴 危害等级**：⭐ **比"跑得慢"严重得多** —— ⚠️ 它会产出一个**看起来有证据的错误根因**，⭐ 然后把我引向"去改容限"这种掩盖症状的方向（⭐ 而仿真已证明 48/96 完全够用）。<br>**📌 另一条同族教训**：⭐ 我一度"读代码"认定 `S_VOTE`→`S_FIRE` 会丢最后一帧的 `vmin/vmax`，🔴 **专门写 tb 去证 ⇒ RTL 是对的** ⇒ ⭐ **假说被自己的实验推翻** ⇒ ⭐ **"读代码猜根因"不可靠，必须让 tb 说话**。<br>**⚠️ 顺带查实**：⭐ `stable_cnt` 实际需要 **`STABLE_NEED + 2` 帧**（⛔ 不是 `STABLE_NEED` 帧）—— ⭐ 前 2 帧被 `prev_val = 12'hFFF` 初值吃掉（⭐ 第 1 帧跳过比较、第 2 帧才 +1）⇒ ⚠️ 参数注释有误导，⛔ 但不影响功能（⭐ 上板余量 200 倍）。 | tb（`tb_span_realistic` 等） | ✅ **已固化为纪律**（⭐ 保留 `tb_span_realistic` 作同比例判据；⭐ 删掉 3 支短超时的误导性 tb） |
| **K-130** | 🔴⭐ **`edit` 工具会【剥掉】`.ps1` 的 UTF-8 BOM ⇒ 一次小编辑就把整个脚本变成 `C72` 违规**（2026-09-25 实测） | **现象**：⭐ 我用 `edit` 往 `sim/tb_all.ps1` 的 `$heavyTb` 数组加了 **1 行**，⭐ 然后编码守卫报：<br>`[FAIL] sim\tb_all.ps1   BOM=no  non-ASCII=7101`<br>**🔴 根因（⭐ 字节级实测）**：· ⭐ `git cat-file` 取出的**版本首 3 字节 = `EF BB BF`**（✅ 有 BOM）；· ⭐ 我 `edit` 之后 ⇒ **首 3 字节 = `23 20 74`（`# t`）** ⇒ 🔴 **BOM 没了**。<br>⇒ ⭐ **`edit` 写回时按无 BOM 的 UTF-8 写** ⇒ 🔴 一次"只加一行"的编辑，把 **7101 个非 ASCII 字节**的脚本变成违规文件。<br>**⚠️ 为什么危险**：⭐ 这是 `C72` 的**新触发路径** —— ⚠️ 以前防的是"新建脚本忘了加 BOM"，🔴 **现在连"编辑既有合规脚本"都会踩**。⭐ 而 `C72` 的后果是**静默丢数组元素**（⭐ 我这次正好改的就是数组！）⇒ 🔴 **可能让重 tb 超时预算悄悄少一项**。<br>**✅ 修法（⭐ 已执行）**：⭐ `powershell -File tools\add_ps1_bom.ps1 -Apply`（⭐ 仓库自带，⭐ 先干跑再 `-Apply`）⇒ ⭐ 首字节恢复 `EF BB BF`，⭐ 守卫 `exit 0`。<br>**📌 固化为纪律**：🔴 **每次用 `edit` 改过 `.ps1` 之后，必须立刻跑 `tools\check_ps1_encoding.ps1`**（⭐ ⛔ 不要等到提交前）。<br>📌 **佐证**：⭐ `git diff --numstat` 显示 **1 insertion / 0 deletions** ⇒ ⭐ **内容本身没被改坏，确实只差 BOM**（⭐ 说明行尾也完好，⛔ 不是 `C76`）。 | 工具链（`edit` + `.ps1`） | ✅ **已修 + 已固化纪律** |
| **K-132** | 🔴🔴⭐ **`need_press_o` 卡在高位不落 ⇒ `ev_need` 上升沿只产生 1 次 ⇒ `'S'` **只回 `s`、永远不回轴号**（2026-09-25 上板实测 + 仿真定案）** | **现象（⭐ 用户实测）**：⭐ 发 `'S'`（⭐ 连发 8 次）⇒ 🔴 **只回一个 `s`，⭐ 没有轴号，⭐ 也没有 `!`**。⚠️ 而 `'P'`（读 ADC）和 `'V'`（读状态）都正常。<br>**🔴 根因（⭐ 读码 + 仿真双证）**：· `calib_span.v` 的 `S_PROMPT` 原来是 `need_press_o <= 1'b1;` … `state <= S_SETTLE;` —— ⭐ **同拍就离开**；<br>· ⭐ 而 `S_SETTLE` / `S_VOTE` / `S_FIRE` **都没有** `need_press_o` 赋值 ⇒ ⭐ **它一直保持 1**（⭐ 直到 `S_WAITBUSY`/`S_DONE`/`abort` 才清）；<br>· 🔴 `top.v` 用的是**上升沿检测**：`ev_need = sp_need_press & ~sp_need_r` ⇒ `rep_byte = ev_need ? axis_char : …`；<br>· ⇒ 🔴 **超时重试回到 `S_PROMPT` 时 `need_press_o` 本来就是 1** ⇒ ⭐ **没有 0→1 跳变** ⇒ 🔴 **`ev_need` 不再产生 ⇒ 轴号永不回发**。<br>**📌 仿真实测（⭐ 决定性）**：⭐ `tb_span_retry_reemits_axis` 制造 9 次重试：<br>· 🔴 **修复前**：⭐ 进 `S_PROMPT` **9** 次 ⇒ `ev_need` **只有 1** 次 ⇒ 🔴 **轴号只发 1 次**（⭐ 与上板现象完全一致）<br>· ✅ **修复后**：⭐ **9 次 ⇒ 9 次**（⭐ 每次都重发轴号）<br>**⚠️ 为什么以前没发现**：⭐ 原 `tb_calib_span` / `tb_uart_calib_chain` 只判"`need_press_o` 拉起来了"（⭐ 真），🔴 **但从没判"轴号真的发出去了几次"** ⇒ ⚠️ **判据存在盲区**（⭐ `K-87` 同族：**看得见状态，看不见结果**）。<br>**✅ 修法**：⭐ `S_PROMPT` **停留 2 拍**（⭐ 新增显式标记 `prompt_phase`）：第 1 拍 `need_press_o <= 0`（⭐ 造下降沿）、第 2 拍 `need_press_o <= 1`（⭐ 干净上升沿 ⇒ `ev_need`）。📌 **为什么用显式标记而不是"数拍子"**：⭐ 数拍子在重构时会静默漂移；⭐ 标记让**意图写在代码里**。⭐ 复位与 `abort_i` 分支都清零该标记。<br>**📌 回归保护**：⭐ 新增 `tb_span_retry_reemits_axis`（⭐ 判据 = `ev_need` 次数 ≈ 进 `S_PROMPT` 次数）⇒ 🔴 **改回单拍逻辑会让它立刻变红**（⭐ 已反向验证）。 | RTL（`calib_span.v`）+ tb | ✅ **已修**（⭐ 2026-09-25；⭐ 反向验证通过：旧码 FAIL / 新码 PASS） |
| **K-133** | ⚠️⭐ **`span_probe` 的 `'V'` 输出里 `idx4` 是【硬编码常量 `'0'`】⇒ 会把输出伪装成"4 位 reject"**（2026-09-25 解读上板 `V7090` 时发现） | **事实**：⭐ `span_probe.v` 的字节布局是 `V` + `state` + `axis` + `hexch(rj_lat)` + 🔴 **常量 `8'h30`** + CR + LF。<br>🔴 **设计时的误解**：⭐ 当时以为 `reject_cnt` 需要 2 位 hex，⚠️ **但它其实是 `reg [3:0]`（0~15）** ⇒ ⭐ 1 位 hex 就够 ⇒ 🔴 **`idx4` 那个 `'0'` 是多余的**。<br>**⚠️ 危害**：⭐ 输出长得像"`V<state><axis><rej 2 位>`"，🔴 **极易被误读**（⭐ 我第一次就把 `V7090` 解成了 `rej=0x90=144`，⚠️ 实际是 `state=7 / axis=0 / rej=9`）。<br>**✅ 建议修法**：⭐ 把 `idx4` 改成回**别的有用信息**，⭐ 例如 `hexch(vote_cnt)`（⭐ 投票进度：⭐ 卡在 VOTE 时能看出收了几帧）或 `cal_busy_i`/`cal_err_i`（⭐ 看 `calib` 的反馈）。<br>📌 **优先级**：⚠️ 低（⭐ 只是诊断可读性，⛔ 不影响功能）—— ⭐ 但**与 `'V'` 扩展一起做最划算**。 | RTL（`span_probe.v`） | ⬜ **待办** |
| **K-134** | 🔴⭐ **变异测试被强杀后会留下【残留变异】污染后续回归 —— 而"我刚好改过代码"会让它伪装成自己的 bug**（2026-09-25 实测） | **现象**：⭐ 我刚改完 `top.v`（外置 DAC）⇒ 全量回归报 **60/61**，⭐ 失败项是 `tb_checkers` 的 **A4/A5/A4c 负向测试失效**。<br>**🔴 真因**：⭐ 先前一条命令**超时被强杀**，⚠️ 而它当时正在跑变异测试 ⇒ 🔴 **一个变异体没被还原**：<br>`tb/checkers/chk_at_most_one.sv` 的 `if (n_active > 1)` ⇒ 🔴 **被改成 `if (n_active > 99)`** ⇒ ⭐ 负向测试永远报不出来。<br>**🔴 触发条件（⭐ 我的失误）**：⭐ 我以为 `mutation_test.ps1 -Filter M11` 只是"列出来"，⚠️ **实际它会真跑**（⭐ 每个变异体跑一遍全量回归）⇒ ⚠️ 180 秒超时被强杀。📌 ⭐ **该脚本【没有】`-ListOnly`/dry-run 参数** —— ⭐ 用之前**必须读源码确认**。<br>**✅ 修复**：⭐ `git checkout -- tb/checkers/chk_at_most_one.sv` + ⭐ 清 `build/mutation/backup/*.bak`。⭐ 判据：⭐ `git status` 里 `tb/checkers/` 必须为空。<br>**⭐ 三条教训**：① 🔴 **先 commit 再跑变异测试**（⭐ 项目规则早写了 —— ⚠️ 因为脚本**就地改可跟踪文件**，被杀后**分不清残留与己改**；⭐ 本次**能定位**恰恰是因为有 commit 做基准）；② 🔴 **别把"看参数"当"干跑"**（⭐ 先读脚本确认）；③ ⭐⭐ **"我刚好改过东西"会让残留污染伪装成自己的 bug** ⇒ ⭐ **先 `git status`**，⭐ 看 FAIL 涉及的文件**有没有我没动过的改动**（⭐ 本次 FAIL 在 `tb_checkers`，⭐ 我根本没碰 ⇒ 🔴 **立刻排除自己**）。 | 流程（变异测试 + git 纪律） | ✅ **已修复 + 已登记** |
| **K-82** | 🔴⭐ **`timbre` 是"全局参数"而不是"每 voice 属性" —— looper 的"一层一件乐器"用法做不出来**（2026-09-20 设计 looper 时发现） | 事实：`files/20-代码/W3接口冻结表.md` §三 里 **`note_evt_t`（事件通路）⛔ 不含 `timbre`**，只有 `expr_param_t`（参数通路）含 `timbre[3:0]` ⇒ ⭐ **`timbre` 是"全局持续参数"**。⚠️ 后果三个：① **录吉他 → 切钢琴 → 播 loop ⇒ loop 变成钢琴声**；② **播 loop 中途切音色 ⇒ 整个 loop 集体变声**；③ 🔴 **"贝斯层 + 吉他层 + 钢琴层同时播"根本做不到**（三层只能是同一个音色）⇒ ⭐ **直接否掉"3 层 = 3 件乐器"这个核心用法** | RTL + 接口 | 🔴 **looper 的"一层一件乐器"用法、`note_manager`/`osc`/`wavetable` 接口** | ✅ **已改（2026-09-20）**：① `files/20-代码/W3接口冻结表.md` §三 接口 ② 的 `timbre` 语义改为「**新起音的默认音色**」，⭐ **每个 voice 起音时锁存自己的 `timbre`**；② `files/20-代码/音色设计.md` §五 同步更新；③ ⭐ **looper 每层存 `layer_timbre[3:0]`**（`rec_start` 锁存，重放时覆盖）—— 代价 **12 bit**，⛔ 不改 64 bit 事件格式。⚠️ **RTL 侧影响**：`note_manager`/`osc`/`wavetable` 需支持"每 voice 独立音色"（⚠️ **当前 `rtl/` 里无任何 `timbre` 引用 ⇒ 零既有代码受影响**）。⭐ **附带好处**：切换音色不会让正在响的音突变。📌 **`note_evt_t` 不新增字段** |
| **K-136** | 🔴🔴⭐ **`impl/pnr/Gowin2026.fs` 与当前 RTL 【不一致】⇒ 烧板会烧到旧版本，所有上板结论作废**（2026-09-26 计划核对时发现） | **事实（⭐ 文件时间戳实测）**：`.fs` = `22:09:22`，而比它新的 RTL 有 **7 个**：`top.v` / `tdm_render_mixer.v` / `param_extract.v` / `test_mode_ctrl.v` / `note_manager.v` / `metronome.v` / `calib_cmd.v`。⚠️ 且远端刚合入的 **Test Mode（`14e9c68`）** 与未提交的 `nm_gate`/基准 104 改动**都不在**该 `.fs` 里。<br>🔴 **后果**：⭐ 烧上去的是"基准 70 那版" ⇒ 🔴 **上板现象与工作区代码不对应** ⇒ ⚠️ 会拿旧现象去调新代码（⭐ `K-87`/`K-106` 同族：**路径能失败却不可见**）。<br>⭐ **判据（⭐ 机械可查）**：`Get-ChildItem rtl -Recurse -Include *.v \| ? {$_.LastWriteTime -gt (Get-Item impl\pnr\Gowin2026.fs).LastWriteTime}` 必须为**空**。<br>⭐ **对策**：⛔ 任何上板前**必须先重跑 `sim\gowin_build.ps1`**；⭐ 建议做成构建守卫（⭐ 同 `U-31` 的产物新鲜度断言）。 | 构建产物（`impl/pnr/*.fs`） | ⚠️ **需重建后才能复核**（⭐ 本次审计时 `impl\pnr` **不存在**，无法比对；⭐ 上板前必做） |
| **K-137** | 🔴⭐ **`uart_ui.v`（串口屏 = 已拍板的【主控制面】）是【死代码】—— 既不在 `Gowin2026.gprj`、也未被 `top.v` 例化**（2026-09-26 计划核对时发现） | **事实（⭐ 三处实测）**：① `rtl/w3c/uart_ui.v` **存在**，⭐ 且有 tb `tb/w3c/tb_uart_ui.sv` + 证据日志 `sim/evidence/tb_uart_ui.log`（⭐ "看着已完成"）；② 🔴 **`Gowin2026.gprj` 里 grep 不到 `uart_ui`**（⭐ 同批的 `master_mix`/`led_data`/`seq_arb` 都在）；③ 🔴 **`top.v` 里 grep 不到 `u_uart_ui`**（⭐ 只有注释提到）。<br>⚠️ **后果**：⭐ "tb 全绿"但**根本没进综合** ⇒ 🔴 **上板时串口屏完全不可用**；⚠️ 且它输出的 `mode_o`/`base_semi_o`（⭐ **键盘/指板两模式切换**）同样没接 ⇒ ⭐ **`T15` 两种演奏模式在硬件上不存在**（⭐ 与 `K-40` 的"实时性"评分点相关）。<br>📌 **注意**：⭐ 这正是 `U-30` 构建守卫要防的那类问题 —— ⚠️ 但该守卫只查"**被 `top.v` 例化**却不在 `.gprj`"的文件 ⇒ 🔴 **本例"既没例化也不在 `.gprj`"，守卫【查不到】** ⇒ ⭐ **守卫的盲区**。<br>⭐ **对策**：⭐ 归属 **丙**（⭐ `第二周计划-v4` §三 9/27）⇒ ⚠️ **要么接进 `top.v`、要么明确记为未做**，⛔ 不能停在"有文件有 tb 就算完成"。 | RTL（`uart_ui.v`）+ 工程文件 | 🔴 **未接**（⭐ 未进 `.gprj`/未例化） |
| **K-138** | ⚠️⭐ **四音色波表（`T31b`）确认【不存在】，且 `timbre_id_i` 是【惰性输入】—— 已接收但完全不参与逻辑**（2026-09-26 计划核对时复核 `K-86`/`K-82`） | **事实（⭐ 代码级）**：① `rtl/w3b/wavetable_bank.v` = **单块正弦表**（⭐ `case` 常量表 512 点 + `wavetable_sine_rom_ip`；⭐ `ip/` 下只有 `wavetable_sine_rom_ip` 一个 ROM IP），🔴 **全文 grep `timbre`/`TIMBRE_N` 零命中**；② `rtl/w3b/oscillator_bank.v` 的 `TIMBRE_N` **自述** *"`TIMBRE_N`：当前只用于参数校验，⛔ 不影响逻辑（只有一块表）"*；③ `timbre_id_i` 全模块只出现 **3 次**（⭐ 1 次端口声明 + 2 次注释）⇒ ⭐ **惰性输入**；④ 工具 `tools/gen_wavetable_bank.py` 只生成 **512×16 正弦**（⭐ 自述 *"deterministic sine wavetable"*）。<br>🔴 **后果**：⭐ **丢评分项 `T44`（四音色盲听可分）** + ⚠️ **曲谱多声部音色全一样** + ⚠️ `K-82`（`timbre` 应是每 voice 属性）未解决。<br>⚠️ **同模块还有 3 个惰性输入**：`fm_cfg_valid_i`/`fm_ratio_i`/`fm_index_i`（⭐ `ENABLE_FM=0`，⭐ `A2c` 已声明"先留接口、后加，不计入吞吐量"）⇒ ⭐ **这是【有意留位】**，⛔ 不算缺陷，⚠️ **但要记得它不工作**。 | RTL（`wavetable_bank.v` / `oscillator_bank.v`） | ✅ **已做**（⭐ 4 音色 × 1024 点 × soft/hard，**10 张 pROM**；`wavetable_bank.v` 的 `T31b generated ROM` 头注释 / `TIMBRE_N`） |
| **K-139** | ⚠️⭐ **`T55`/`T56` 在任务清单里标"未完成"，但代码【早已实装】—— 账实不符，会误导排工**（2026-09-26 计划核对时发现） | **事实**：⭐ `rtl/w3b/oscillator_bank.v`（⭐ 64 lane `generate` 展开、每 lane 独立 `phase_q`/`addr_q`）与 `rtl/w3b/tdm_render_mixer.v`（⭐ TDM 求和 + `gain_sqrt_lut` + 限幅）**都已去桩实装**，⭐ 且**都在 `Gowin2026.gprj` 里**、⭐ 都被 `top.v` 例化（⭐ `u_oscillator_bank` = `top.v` 的 `oscillator_bank` 例化）。<br>🔴 **后果**：⚠️ 与 `U-3`（Test Mode 空桩）**同族** —— ⭐ **文档落后于代码** ⇒ ⚠️ 接手人会**重复劳动**或**误判进度**。<br>⭐ **对策**：⭐ 回填任务清单 `T55`/`T56` 状态；⭐ 并把 `未完成工作总账.md` §〇 的 **"回归 63/63"** 更正（⚠️ `tb/` 实测已有 **83 个** `.sv`）。 | 文档（任务清单 / 总账） | 🔴 **账实不符** |
| **K-140** | 🔴⭐ **`param_extract` 的 `DT_MAX = 64` 仍是【未修】状态，而它是"按键音量偏小"的真因①（上游）**（2026-09-26 计划核对时复核 `K-124`） | **事实（⭐ 代码级）**：`rtl/w3a/param_extract.v` 的 `DT_MAX` 当前仍是 `parameter integer DT_MAX = 64`，⭐ 且 `VEL_MIN = 8'd64`、`VEL_MAX = 8'd255`。⭐ 模块注释**自述**：*"`Δt >= DT_MAX` ⇒ 力度取**最小**"*。<br>🔴 **物理含义（⭐ 按实测帧周期 500 µs，见 `K-128`）**：`64 × 500 µs = 32 ms` ⇒ ⚠️ **只有"从静止起按得极快"才越过阈值**；⭐ 而**正常演奏 `Δt`（按下到抬起的时长）远大于 32 ms** ⇒ 🔴 **力度恒为 `VEL_MIN=64`** ⇒ ⭐ **力度功能静默失效**。<br>⭐ **与交接文档的关系**：⭐ 交接文档 §二 记的"真因① `vel_upd` 把力度从 200 压到 64"⭐ **已于 `c8b243f` 修**（⭐ 改成"只允许调大"）⇒ ⚠️ **但那是【下游】补丁**；🔴 **【上游】`DT_MAX` 超量程【没修】** ⇒ ⭐ **力度仍然恒为最小值**，⭐ 只是不再被二次压低。<br>⭐ **对策**：⭐ 按真实按键时长（`10~50 ms`）反算 ⇒ `DT_MAX` 降到 **20~100** 之间（⚠️ 必须按 `K-128` 的 **500 µs** 真实帧周期重算，⛔ 不要沿用旧 196 µs 口径）。 | RTL（`param_extract.v`） | ⚠️ **不在通路上**（⭐ `param_extract` 的力度输出**有意不用**，`top.v` 的「`param_extract` 力度三件套有意不使用」注释）⇒ ⭐ **本条不再是真因** |
| **K-141** | ✅⭐ **【2026-09-30 已更正】`constr/top.cst` 实际是【UTF-8 无 BOM ＋ LF】—— 原判"GBK 编码"有误；⚠️ 但"`.cst` 无编码守卫"这一点【仍成立】**（2026-09-26 发现 · 2026-09-30 更正） | **🔴 原结论（⛔ 保留痕迹，⭐ 已被实测推翻）**：⭐ "读取 `constr/top.cst` 时中文注释**全部乱码**（⭐ 例：`// 鈹€鈹€鈹€鈹€ 寮曡剼绾︽潫`）⇒ 该文件是 **GBK 编码**"。<br>✅ **2026-09-30 实测更正（⭐ 字节级）**：⭐ `constr/top.cst` = **UTF-8【无 BOM】＋【纯 LF】** —— ⭐ 首 3 字节 = `47,47,32`（`// `，⛔ 不是 `EF BB BF`）· ⭐ 行尾 **LF 465 / CRLF 0** · ⭐ 非 ASCII 字节 **17654**（⭐ 全部是合法 UTF-8 中文注释）。<br>🔎 **为什么当初会看成乱码**：⭐ **不是文件的错，是【读取方】的解码选择** —— ⚠️ PS 5.1 的 `Get-Content` **默认按 GBK 解码**无 BOM 的 UTF-8（⭐ 见 `C72`/`K-38`）⇒ ⭐ **任何无 BOM 的 UTF-8 文件用默认参数读都会"乱码"**（⭐ `C17`：**BOM 归属由读取方决定**）。⭐ 本次改用 `ReadAllBytes` / `Get-Content -Encoding UTF8` 读取 ⇒ ✅ **中文完全正常**。<br>⚠️ **仍然成立的部分（⭐ 本条的价值所在）**：🔴 **`.cst` 依旧没有任何编码守卫**（⭐ `tools/check_ps1_encoding.ps1` 只管 `.ps1`）⇒ ⭐ **将来谁把 `top.cst` 存成 GBK 或加上 BOM，没有机械检查能发现**。<br>⚠️ **后果（不变）**：⭐ 该文件含**大量关键引脚语义**（⭐ `PA_EN_n=Y14` 的 `SD_MODE` 多电平说明、`I2S2_*` 的外置 DAC 接线、`uart_rx/tx` 的 `J9 N25/N26`、`led_oe_n[4:0]`、Bank 电压 **1.5 V vs 3.3 V**）⇒ 🔴 **若有人按乱码误读，可能接错线或写错 `IO_TYPE`**（⭐ 写错 Bank 电压**可能损伤 IO**，⭐ 见 `U-25b`）。<br>⭐ **对策（⭐ 已收窄）**：⭐ ① ⛔ **不需要"把文件转码"**（它本来就是对的）—— ⭐ **要改的是【读法】**：读 `.cst` 一律 `-Encoding UTF8` 或 `ReadAllBytes` ✅；⭐ ② ⭐ **把编码守卫扩到 `.cst`**（⭐ 判据 = "UTF-8 且无 BOM 且 LF"）⇒ ⭐ 这才是本条真正的待办。⚠️ 改动 `.cst` 前先确认 Gowin 对编码的要求，⛔ 不要盲改。 | 约束文件（`constr/top.cst`） | ✅ **原判已更正（2026-09-30）** · ⚠️ **"`.cst` 无编码守卫"仍未处理** |
| **K-142** | ⚠️⭐ **`origin/wip/yi-w2-lfo` 分支【未合入 main】：`T18` 颤音 LFO + 右手板 ADC 控制不在交付版本里**（2026-09-26 计划核对时发现） | **事实**：⭐ `git log origin/wip/yi-w2-lfo` 显示 `06f538a feat(vibrato): 右手板 ADC 控制 + 颤音 LFO 接入 (T18)`，⭐ 其父提交是 `14e9c68`（⭐ 即 Test Mode 那版）⇒ ⭐ **该分支领先 main 1 个提交**。<br>⚠️ **后果**：① ⭐ `T18`（颤音 LFO）在 main 上**不存在** ⇒ ⚠️ 与 `oscillator_bank` 里已有的 `vibrato_mod_i` 端口**接的是常量**（⚠️ 颤音功能实际不工作）；② ⭐ **右手板 ADC 控制**未进 main ⇒ ⚠️ 右手板那一侧的验证**不在当前交付范围内**（⭐ 与 `N_ADC=2`/`AXIS_TOTAL=16` 的现状一致）。<br>⭐ **对策**：⭐ **需用户拍板是否合入**（⭐ 合入要重跑回归 + PnR，⚠️ 且 `Fmax` 余量只剩 **6.6%**）。 | 分支（`wip/yi-w2-lfo`） | ⚠️ **待拍板** |
| **K-143** | ⚠️⭐ **`T64` 的"27 个 tb 缺看门狗"实测口径不符：按 `$finish`/超时关键字统计实为 12 个，且那 12 个【全是模型/检查器，本就不该有】**（2026-09-26 计划核对时实测） | **事实（⭐ 机械统计）**：⭐ `tb/**/*.sv` 共 **83** 个，⭐ 而**回归器实际只跑 `tb_*.sv` 共 71 个**（⭐ `sim/tb_all.ps1:65` 的 `-Include tb_*.sv`）；⭐ 含 `$finish`/超时关键字者 **71**，⚠️ **不含者 12**：`chk_at_most_one` / `chk_deadline` / `chk_fanout_same` / `chk_le_shift` / `chk_min_pulse` / `chk_phase_advance` / `chk_same_net` / `chk_xprop` / `bounce_src` / `i2s_rx_model` / `mcp3208_model` / `wavetable_sine_rom_ip_model`。<br>⭐ **判定**：🔴 **这 12 个【不是 tb 主体】** —— ⭐ 8 个是**检查器**（`chk_*`，⭐ 被 `tb_checkers` 例化）、⭐ 4 个是**模型**（`*_model`/`bounce_src`）⇒ ⭐ **它们由宿主 tb 的看门狗兜底，⭐ 单独加超时没有意义**。<br>⚠️ **结论**：⭐ `T64` 原写的"**27 个无看门狗**"⭐ **与当前统计不符**（⭐ 可能是口径不同，⭐ 或曾被部分修复）⇒ ⭐ **该任务的实际剩余量需重新核定**，⛔ 不要照 27 个排工。<br>⭐ **顺带更正**：⭐ "回归基数"的权威值是 **71 个 `tb_*.sv`**（⭐ ⛔ 不是 `tb/**` 的 83 —— 那 12 个是非 tb 的模型/检查器）⇒ ⚠️ 总账"63/63"、·交接文档"66/66"、⛔ 都不等于当前基数。 | tb（`tb/**`）+ 回归器 | ⚠️ **口径待重核** |
| **K-148** | ⭐⭐ **失谐（detune）已实装 —— `K-95` 的"同 voice 两 lane 失谐未实装"【已过时】**（⭐ 2026-09-26 深夜工作区实测，⭐ **未提交**） | **事实（⭐ 代码级，⭐ `rtl/w3b/oscillator_bank.v`）**：① ⭐ 新增参数 **`DETUNE_ON`（默认 1）** 与 **`DETUNE_SH`（默认 8）**；② ⭐ **`detune_off`**：⭐ `OSC_IDX != 0` 时 `base_inc >> DETUNE_SH`（⭐ **纯移位，⛔ 无乘法器** ⇒ ⭐ 不占 DSP）；③ ⭐ `lane_inc = base_inc + detune_off + vib_off` ⇒ ✅ **两个 lane 频率【不同】** ⇒ ⭐ **拍频** ⇒ ⭐ 叠加从"严格 ×2"变成**非相干**；④ ⭐⭐ **另有"去相关初相"**：`phase_seed` 给 `OSC_IDX==1` 一个 **1/4 周期**（`32'h4000_0000`）初相，⭐ 复位时 `phase_q <= phase_seed`（⛔ 不是全 0）⇒ ✅ **消除起音瞬间的相干尖峰**（⭐ 学自 `xls32` 的"decorrelated start phase"）。<br>⭐ **数值**：`DETUNE_SH=8` ⇒ 偏移 **1/256 ≈ 0.391% ≈ 6.7 cents**（⭐ 注释给的理由：5~15 cents 是"温和 detune"区间）。<br>🔴 **状态**：⭐ **工作区未提交**（⭐ 文件 mtime `22:26`）⇒ ⚠️ **尚未跑回归 / 变异 / PnR**，⛔ **不能视为已验证**。<br>⭐ **对上游结论的影响**：⭐ `K-95` 第②条（"失谐未实装"）**已被本条取代**；⭐ 且 `tdm_render_mixer.v` 的 `>>>1`（lane 取平均）与失谐**目的重叠** ⇒ ⚠️ **两者叠加会让单 voice 幅度降到 1/2 且不再相干 ⇒ 增益基准须重算**（⭐ 现基准 104 是按"相干 ×2"推的）。 | RTL（`oscillator_bank.v`，未提交） | ⚠️ **已实装 / 未验证** |
| **K-149** | 🔴⭐ **工作区存在【跨来源的未提交 RTL 改动】：`oscillator_bank.v` 的改动手工核对时并不存在，随后才出现 ⇒ 与当前会话的判断基线不一致**（2026-09-26 计划核对时发现） | **事实（⭐ 时间线）**：① 我在本轮**早先**读 `oscillator_bank.v` 时，第 130-133 行仍是 `lane_inc = base_phase_inc_i[...] + vib_off`（⭐ **无 detune**），⭐ `grep DETUNE` **零命中**；② 随后我写文档期间，⭐ 该文件 **mtime 变成 `22:26:10`**、⭐ 体积 **22145** 字节，⭐ 且 `git status` 里多出 **`M rtl/w3b/oscillator_bank.v`**（⭐ `80 insertions / 4 deletions`）。<br>🔴 **后果**：⭐ **同一次核对会话里，同一文件的结论发生了变化** ⇒ ⚠️ 任何"基于早先读取"的结论（⭐ 包括本文档的初稿）**可能已过时**。<br>⭐ **对策（⭐ 固化为纪律）**：⭐ **报告前必须重新 `git status` + 对比 mtime**，⭐ 并明确区分"**已提交**"与"**工作区未验证**"两种状态 —— ⛔ 不要把未提交/未验证的代码当成既定事实。<br>📌 **当前工作区未提交的 RTL 共 4 个**：`rtl/top.v`（+71/-7）· `rtl/w3a/param_extract.v`（+26/-2）· `rtl/w3b/oscillator_bank.v`（+80/-4）· `rtl/w3b/tdm_render_mixer.v`（+123/-40）。 | 工作区（`git status`） | 🔴 **基线漂移已记录** |
| **K-144** | 🔴⭐ **`perc_env_bank.v`（专为打击乐新建的"一击到底"包络）从未被任何模块例化 —— 是【孤儿模块】；鼓机/节拍器仍用【慢 ADSR】出声**（2026-09-26 计划核对时发现） | **事实（⭐ 三处实测）**：① `rtl/w3c/perc_env_bank.v` **存在**（⭐ 且 `T33` 的头注释详述了"为什么必须新建它"——⭐ `adsr` 衰减到 sustain 要 **197 ms** 且**停住不归零**，而打击音只要 **10~20 ms**）；② 🔴 **全仓库 grep `perc_env_bank` 只在注释里出现**（⭐ `metronome.v` 的三处 `perc_env_bank` 注释），⭐ **无任何 `perc_env_bank u_...` 例化**；③ 🔴 **`metronome.v` 自己的注释承认**：*"⚠️ **本周先不做**（那要改队友的链），先让 click 走**现有 ADSR** 出声"*。<br>🔴 **后果**：⭐ **打击音（节拍器 click / 鼓机 Kick/Snare/Hi-hit）用的是 ADSR 语义** ⇒ ⚠️ **衰减到 sustain 后【停住不归零】**，⭐ 要等 `note_off` 才停 ⇒ ⚠️ 与"一击到底、自然消失"的打击乐听感**不符**（⭐ 这正是 `perc_env_bank` 被建出来的理由）。<br>📌 **与 `K-95`/失谐的区别**：⭐ `K-95` 是**有意的接口取舍**；🔴 **本条是"建好了但忘了接"** —— ⭐ 模块**有头注释、有设计依据、有参数化**，⚠️ **却零调用** ⇒ ⭐ **`K-87`/`K-106` 同族（做了但不可见）**。<br>⭐ **对策**：⭐ 接进渲染链（⚠️ 需要按"哪些 axis 属打击乐"分流包络）⇒ ⚠️ **属结构性改动，需评估**；⭐ 或**明确记为未做**并保留模块。 | RTL（`perc_env_bank.v` / `top.v`） | ✅ **已修（2026-09-28）**：<br>⭐ **触发条件**：⭐ 用户要求"把节拍器加回来" ⇒ ⭐ `METRONOME_ON` `0 ⇒ 1` ⇒ 🔴 **潜伏缺陷立刻变成可听 bug**（⭐ 用户上板原话：*"开了节拍器之后会挂音"*）。<br>⭐ **修法（最小改动，⛔ 不动任何已验证模块的行为）**：⭐ 在 `top.v` 里把**保留池 voice 的包络电平**从 `envelope_bank` 的 ADSR 换成 `perc_env_bank` 的输出（⭐ 纯位选：`env_level_mix` 的**高 5 路**换掉、**低 27 路逐位透传**）⇒ ⭐ `note_manager` / `oscillator_bank` / `tdm_render_mixer` / `envelope_bank` / `adsr` / `metronome` 的**逻辑一行不改**。<br>⭐ **触发必须用上升沿**（`nm_gate & ~nm_gate_d`）—— ⚠️ `nm_gate` 是**电平**，直接接 `trigger_i` 会每拍重装峰值 ⇒ 🔴 又变挂音；⭐ 而 `voice_gate_o = gate_mask = gate_r & ~retrig_low` ⇒ ⭐ **同轴重触发时会真的压低再抬起** ⇒ 上升沿对"起音"与"重触发"都能触发 ✅。<br>⭐ **键盘音量不受影响**（⭐ 已核实）：`tdm_render_mixer` 的 `popcount` 本来就排除保留池（`.RESERVED_N` ⇒ `NORMAL_N`，见该文件 `:449-476`）。<br>⚠️ **踩坑记录**：第一版用 `generate for` ⇒ 🔴 iverilog 报 *"generate/endgenerate regions cannot nest"* —— ⭐ 因为 `g_sound` **本身就在 `generate` 块里**（`generate`@694 → `endgenerate`@2861）⇒ ⭐ 改成**纯位选**（⛔ 无循环）。 |
| **K-145** | 🔴⭐ **`play_seq.v`（变速播放 + 按 tick 吐事件）是【孤儿模块】—— `top.v` 自己标注"尚未例化"⇒ 曲谱只能靠 `evt_uart_rx` 被动收，⛔ 不能变速**（2026-09-26 计划核对时发现） | **事实（⭐ 代码级）**：① `rtl/w3c/play_seq.v` 存在（⭐ 且 `U-7`/`U-18` 记录它"已完成并修了三个真缺陷"、⭐ 变异体 M69~M72 全 CAUGHT）；② 🔴 **`top.v` 的 `guide_key` 注释自己写着**：*"`guide_key`（哪些键该按）→ 正确来源是 `play_seq`，但**尚未例化**（甲）"*，⭐ `top.v` 的 `u_led_data` 例化接的是 `.guide_key_i (16'd0)` —— ⭐ **占位常量**；③ 🔴 全仓库**无 `play_seq u_...` 例化**。<br>⚠️ **后果**：① ⭐ **`U-7` 变速播放（tempo 事件）在硬件上不可用**（⚠️ 而实测"3 个谱子里 2 个变速" ⇒ ⭐ 灌真实曲谱会**按错误速度播放**）；② ⭐ **LED 演奏指引（`guide_key`）永远是 0** ⇒ 🔴 **"该按哪个键"的指引功能不存在**（⚠️ 这是个**演示看点**）；③ ⚠️ 曲谱通路虽已由 `seq_arb` 接通（⭐ `U-34`），⭐ 但**没有 `play_seq` 就没有"按 tick 节奏推进"** ⇒ ⚠️ 事件的**时间轴**不成立。<br>⭐ **对策**：⭐ 例化 `play_seq` 并接 `beat_gen.tick`/`seq_arb` 源 2/`guide_key`（⭐ 模块与冻结契约都已在）⇒ ⚠️ 但需重跑回归 + PnR（⭐ 余量仅 **6.6%**）。 | RTL（`play_seq.v` / `top.v`） | 🔴 **孤儿（未例化）** |
| **K-146** | ⚠️⭐ **`debounce.sv` 是【孤儿模块】—— 未进 `top.v`；而 `T14` 在任务清单里标"已完成（13/13 过）"**（2026-09-26 计划核对时发现） | **事实**：① `rtl/drivers/debounce.sv` 存在（⭐ 丙的 `T14`，⭐ `tb_debounce` 13/13 过、⭐ 变异体 M19 被抓）；② ⭐ 在 `Gowin2026.gprj` 里 ✅；③ 🔴 **但全仓库无 `debounce u_...` 例化**、⭐ `top.v` 里 grep 不到。<br>⚠️ **后果**：⭐ **EC11 旋钮 + 4 按键的去抖在硬件上不存在** ⇒ ⚠️ 若外设直接进 `top.v` 会**读到抖动**（⭐ 与 `K-40` 实时性、`T15` 两模式切换都相关）。<br>📌 **归因**：⭐ 可能**本来就还没排到接**（⭐ 左手板/右手板实物才刚可用）⇒ ⚠️ **标注为"未接"而非"缺陷"**，⭐ 但要防止被 `T14` 的 ✅ 误导。 | RTL（`debounce.sv` / `top.v`） | 🔴 **孤儿（未例化）** |
| **K-147** | 🔴⭐ **`T31`（波表上板最小验证）在任务清单里【没有任何勾选痕迹】，而它是"所有出声功能的前提"**（2026-09-26 计划核对时发现） | **事实**：① ⭐ `第二周任务清单.md` §零 明写 *"`P3`（波表验证）**必须排在出声链前面**：⚠️ `$readmemh` 外部 `.mem` 在 GW5AT-60 **不加载** ⇒ ROM 全 0 ⇒ **没声音，但仿真全对**"*；② ⭐ `未完成工作总账.md` 的 `U-4` 状态仍是 **🔴 待做（⚠️ 等板子）** —— ⚠️ **但板子 9/23 已到手** ⇒ ⭐ **该阻塞理由已失效**；③ 🔴 **`rtl/` 里 grep `readmemh`/`.mem` 零命中**、⭐ `ip/` 下只有 `wavetable_sine_rom_ip` ⇒ ⭐ 说明**当前走的是 pROM/case 路径**，⚠️ **但"pROM 在真硅片上到底加载不加载"仍未实测**。<br>⚠️ **后果**：⭐ **上板"没声音"时无法区分【波表没加载】还是【集成问题】** ⇒ 🔴 这正是 `T31` 要消除的歧义，⛔ 至今没消除；⚠️ 且 `U-4` 的"等板子"理由**已过期**，会让人以为它还被阻塞。<br>⭐ **对策**：⭐ 上板时**优先做"波表活体见证"**（⭐ 例如让 ROM 内容驱动一个可观测输出/LED 图案），⭐ 或直接把 `U-4` 的阻塞理由更正为"未排期"。 | 任务清单（`T31` / `U-4`） | 🔴 **未做 + 阻塞理由过期** |
| **K-150** | 🔴⭐ **"偶发尖音"（B2）在【非常用力地敲打磁轴】时仍可复现 —— 正常使用不会出现，但未根除**（⭐ 2026-09-28 用户上板实测反馈，⭐ 用户同意**暂时搁置**） | **现象（⭐ 用户原话）**：*"非常用力地敲打磁轴，还有可能发出之前修复过的尖音，虽然这种情况在正常使用过程中不会出现，但是如果可以修正好那更好"*。<br>**已做的修复**：⭐ `B2-a`（`retrig_reset_r` 电平化，`note_manager.v`）+ ⭐ `same_hit` 改用 `live_mask` ⇒ ⭐ 已消除**同键快速重按**那条主路径（⭐ 判据：40 ms 内重按 ≥30 次）。<br>🔴 **本轮实测说明还有【残余路径】**。<br>**两个已量化的候选（⭐ 都**还没修**）**：<br>① ⭐⭐ **`tdm_render_mixer.v`：`n_active==0 ⇒ gain=88`（表内【最大】增益）**，且增益是**自由运行寄存器**、与样本**不同源**（差 2~3 拍）⇒ ⚠️ `n_active` 瞬时读到 0 时增益**跳到最大** ⇒ 🔴 幅度尖峰 ⇒ 尖音（⭐ 该文件自己把它列为"**头号候选**"，见 `修复记录总结-20260928.md` §十一 / `修复进度-20260928.md` §四）。<br>② ⭐ **`RT_LOW` 的第一拍若撞上 `sample_tick`，`retrig_reset` 漏采** ⇒ ⭐ 同一尖音以 **~1/1024** 概率复现（`审计-note_manager与ADSR-20260928.md:209`）。<br>**⭐ 为什么"非常用力"会提高命中率（⭐ 本轮新增的定量线索）**：<br>· ⭐ 磁轴满行程 ⇒ `pos_to_vel` 饱和到 **255** ⇒ 峰值 `255<<8 = 65280`（⭐ 满幅 **99.6%**）⇒ ⚠️ **任何叠加尖峰都会顶到限幅/饱和**；<br>· ⭐ 用力敲打 ⇒ **同轴快速重触发** + 快速 alloc/release ⇒ ⚠️ **`n_active` 抖动更大**（候选①）+ **更多 `RT_LOW` 窗口**（候选②）。<br>⭐ **对策**：⚠️ **本轮【不修】**（⭐ 用户同意搁置）⇒ ⭐ **登记在此**；⭐ 修法方向见上两条候选。 | RTL（`tdm_render_mixer.v` / `note_manager.v`） | 🟡 **待修 · ⭐ 但两个候选已【双双排除】**（⭐ 2026-09-28 代码核对）<br>🔴 **候选① 排除**：⭐ **结构上不可达** —— `env_level≠0 ⟹ live_mask=1 ⟹ n_active≥1` ⇒ LUT 的 `6'd0: 88` **永不被选中**（⭐ 证明见 `修复记录总结-20260928.md` §十 第 12 行；⭐ 本轮**独立重推**得到同一结论）<br>🔴 **候选② 排除**：⭐ `note_manager.v` 的 `retrig_reset_r` 的 `if (!sample_tick_i)` 守卫**已在**（`B2-a` 修的）；⭐ `ST_COMMIT` 那条路（`:685`）虽无守卫，⚠️ 但 `:463` 的 `if (sample_tick_i) retrig_reset_r <= 0;` 在**同块写在前面** ⇒ ⭐ **后写覆盖先写** ⇒ 置的 1 **保持到下一个 tick** ⇒ **ADSR 必然看见**（⭐ 只晚一帧，⛔ 不是漏采）<br>⭐ **新主嫌（待验）**：⭐ **`1/√N` 增益在【帧边界】阶跃** —— ⚠️ 增益是**加在求和之后**的**单个标量**，`N` 一变就**整条混音乘一个新系数** ⇒ 🔴 **对非零信号就是不连续 = 咔声**；⭐ **完美解释"只有快速/用力弹才出现"**（`N` 变得越频繁，咔声越多）<br>⚠️ **修法代价**：⭐ 要给 `norm_gain` 加**短时间常数 slew**（稳态值不变）—— 🔴 **本项目已踩过**：加一阶斜坡 ⇒ `tb_tdm_render_mixer` **5 条 FAIL** ⇒ 已回退（⭐ **验收 tb 是已交付行为的契约**）⇒ ⭐ **需用户拍板后再动**<br>📌 **离线证据**：⭐ 上板采集已证明**静止时霍尔抖动 = 0**（⭐ 一次 55 s `'N'` 采集，静止段 spread **min=0 max=0**）⇒ ⚠️ **"霍尔本身不稳"排除**；⭐ 但串口轮询只有 **~4 Hz/轴**（实测 247 ms）⇒ ⛔ **看不到 20 ms 瞬态** ⇒ ⭐ **已出 `'Q'` 诊断 build**（FPGA 侧测 `max\|Δpos\|`） |
| **K-151** | ⚠️⭐ **本轮踩到的四个【仿真/语法】陷阱 —— 每个都曾让我误判成"RTL 写错了"**（⭐ 2026-09-28，写 `tb_perc_env_top` / `tb_met_start_top` / `'Q'` 诊断时） | **① 🔴 `force` 不能与 `@(posedge clk)` 同刻**<br>· ⭐ 现象：`gate` 与 `gate_d` **永远显示同拍**、由它派生的 1 拍脉冲**恒 0** ⇒ ⚠️ **看起来像"边沿检测根本没写"**<br>· 🔎 根因：⭐ 与同一时间步的 `always @(posedge clk)` **抢 delta** ⇒ ⭐ 那个脉冲**没落在任何采样点上**<br>· ✅ 修法：`@(posedge clk); #5; force ...;`（⭐ **移到拍中间**）<br><br>**② 🔴 "电平型"激励 ⛔ 不能保持两个 posedge**<br>· ⭐ 现象：⭐ **8 拍却收到 16 个事件** ⇒ 判据全红（⚠️ 而 RTL 是对的）<br>· 🔎 根因：⭐ `beat_i` 是**电平**，而 `metronome` 里是 `evt_valid_o <= fire` ⇒ ⚠️ 保持两个 posedge ⇒ **两拍都置 1**<br>· ✅ 修法：`@(posedge clk); #5; release ...;`（⭐ 只保持**一个** posedge）<br>· 📌 **纪律**：⭐ **`force` 电平型输入时，先问"它要跨过几个 posedge"**，⛔ 不是"我保持多久"<br><br>**③ 🔴 Verilog-2001 ⛔ 不允许对【函数返回值】直接位选**<br>· ⭐ `dpos_abs_f(a,b)[11:0]` ⇒ 🔴 `syntax error` + `Malformed statement`（⭐ 已实测）<br>· ✅ 修法：⭐ 要加宽就在**调用处用拼接**：`{1'b0, dpos_abs_f(a,b)}` ✅<br>· 📌 **同族**：⭐ 函数**不能声明在 `generate` 块里**（⚠️ 本项目的 `g_sound` 已在 generate 块中 ⇒ ⭐ 函数必须放**模块级**）<br><br>**④ 🔴 `generate`/`endgenerate` ⛔ 不能嵌套**<br>· ⭐ 报 `generate/endgenerate regions cannot nest` ⇒ ⭐ 因为 `g_sound` **本身就在 `generate` 块里**<br>· ✅ 修法：⭐ 用**纯位选 / 拼接**代替循环（⭐ `env_level_mix` 就是这么写的） | 验证方法论 + 语法 | ⭐⭐ **"判据红了"到底是谁的错**（`C83` 同族） | ⚠️ **已知陷阱（⛔ 不是待修 bug）**：⭐ 四条都已写进对应 tb 的注释 + 经验库 `U74`<br>📌 **通用纪律**：⭐ **判据红了，先怀疑【激励 / 观测方式】，⛔ 别先改 RTL** —— ⭐ 本轮 **4 次**判据红，**4 次**都是 tb 的问题（⭐ RTL 全对） |
| **K-152** | ⭐⭐⭐ **"尖音"是【一类听感、多种根因】—— 必须先用【四个问题】分诊，⛔ 不要直接找"那个 bug"**（⭐ 2026-09-28 用户提出关键反问后确立） | **⭐ 用户的决定性反问**：*"我们听到的尖音都是**比正常声音大出很多**，而且听感**比较尖锐**，感觉**不是咔哒咔哒的台阶声音**。你的解释是合理的吗"*<br>⇒ ⭐ **这句话推翻了我原来"尖音=波形台阶⇒宽带咔声"的统一解释** ✅（⭐ 台阶通常**不比信号更响**、且听起来是**"咔哒/沙沙"**，⛔ 不是"又响又尖"）<br><br>**⭐ 修正后的两类**：<br>| 听感 | 机制 | 查哪里 |<br>|---|---|---|<br>| ⭐ **"咔哒"**（一次、不特别响） | ⭐ **波形台阶 / 不连续** | ⭐ 同拍问题、状态突变、波表不连续 |<br>| ⭐⭐ **"又响又尖"**（持续、比正常响很多） | ⭐⭐ **削波 clipping** | ⭐ **`gain` 标定 vs 相干 ×2、限幅器工作点、力度饱和** |<br><br>**⭐⭐ 为什么削波恰好解释"又响又尖"**：<br>· ⭐ **"比正常响很多"** ⇒ ⭐ **幅度真的冲上去了**（⛔ 不是小台阶）⇒ 顶到限幅器<br>· ⭐ **"尖锐"** ⇒ ⭐ 削波把波峰**切平** ⇒ 🔴 **大量奇次谐波** ⇒ 尖锐 ✅<br>· ⭐ **"不是咔哒"** ⇒ ⭐ 削波是**持续**的 ⇒ 是"**音色变尖**"，⛔ 不是"一次咔" ✅<br>· ⭐ **"只在用力时"** ⇒ ⭐ 轻按峰值低 ⇒ 不顶限幅器 ✅<br><br>**⭐⭐ 四问分诊表（⭐ 可复用，⭐ 这是本条的核心产出）**：<br>| 问 | 答案 ⇒ 查哪里 |<br>|---|---|<br>| ⭐ **周期性 还是 瞬时？** | **周期** ⇒ 波形/振荡器/波表（跳变随周期重复）<br>**瞬时** ⇒ 事件/包络/增益（跳变由事件触发） |<br>| ⭐ **跟按键力度有关吗？** | **有关** ⇒ **输入链**（`pos`/ADC/力度）<br>**无关** ⇒ **音频链**（增益/包络/混音） |<br>| ⭐ **跟复音数有关吗？** | **有关** ⇒ **混音/归一化/限幅器**<br>**无关** ⇒ 单 voice 内部 |<br>| ⭐ **按住不动就有吗？** | **有** ⇒ **稳态路径**（振荡器/波表/增益）<br>**只在变化时** ⇒ **瞬态路径**（事件/包络） |<br><br>**⭐ 套用实例**：<br>· ⭐ **我们的 K-150**：瞬时 · **力度有关** · 复音无关 · 按住没有 ⇒ ⭐ **输入链** ✅<br>· ⭐ **队友的波表**：**周期** · 力度无关 · **复音有关** · **按住就有** ⇒ ⭐ **波形/波表** ✅<br><br>**⭐⭐ 结构性对策（⭐ 四条，可机械检查）**：<br>① ⭐ 所有"脉冲 + 携带数据"的接口 ⇒ 必须验证**同拍**<br>② ⭐ 所有数值路径 ⇒ **上下限都要夹紧**（⛔ 只夹一边不够）<br>③ ⭐ 所有"会突变"的量（增益/包络/相位）⇒ 必须有**斜坡或迟滞**<br>④ ⭐ 上述每一条 ⇒ 都要有**能失败**的判据<br>⇒ ⭐ **这四条把"尖音"从"偶发谜题"变成"可逐条检查的清单"** ✅ | 验证方法论 + 音频链 | ⭐⭐⭐ **"同一听感、多种根因"怎么分诊** | ⚠️ **方法论条目（⛔ 不是待修 bug）**：⭐ **判据 = "先问四个问题，再决定查哪条链"**<br>📌 **同族**：`K-109`（valid 与载荷差一拍）、`K-151`（四个仿真陷阱）<br>📌 **纪律**：⭐ **⛔ 不许把"尖音"当成一个 bug 去找** —— ⭐ 它是一个**听感家族** |
| **K-154** | ⭐⭐⭐ **"又响又尖"的机制【已闭合】：`note_manager` 的 `vel_r` 可以【一拍跳满】⇒ 包络电平瞬间跳 ⇒ 瞬时过载 ⇒ 削波**（⭐ 2026-09-28，⭐ 由 `probe_headroom` 实测 + 代码追链得出） | **⭐⭐ 证据链（⭐ 三步，⭐ 全部代码级）**：<br>① ⭐ `top.v` `wire [7:0] vu_vel = pos_to_vel(vu_pos);` ⇒ ⭐ `pos` 猛跳 ⇒ `vu_vel` **直接饱和 255**<br>② ⭐ `top.v` 的「`param_extract` 力度三件套有意不使用」注释 *"`param_extract` 的力度三件套现在是【有意不使用】"* ⇒ ⭐ 力度跟随 = **`vu_*` 直接驱动 `note_manager.vel_upd_*`**<br>③ 🔴 `note_manager.v` 的 `vel_upd_valid_i` 分支：<br>```verilog<br>if (vel_upd_valid_i) begin          // ⚠️ 【不在 sample_tick_i 块里】⇒ 每 clk 都能改<br>    ... vel_r[i] <= vel_upd_value_i;  // 🔴 位置式 ⇒ 可【一拍从 64 跳到 255】<br>end<br>```<br>⇒ ⭐ **用力敲打 ⇒ `raw` 跳 ⇒ `pos` 猛跳 ⇒ `vel_r` 一拍跳满 ⇒ 包络电平瞬间跳** ⇒ 🔴 **叠加在正在响的音上 ⇒ 瞬时超限幅器 ⇒ 削波 ⇒ 又响又尖** ✅<br><br>**⭐⭐ 为什么 `probe_headroom` 说"没削波"（⭐ 两者不矛盾）**：<br>⭐ 探针跑的是**正常演奏**（和弦 N=3 / 8 轴 / 16 轴）⇒ ⭐ 峰值 **61.6% FS，余量 38%** ⇒ ✅ **正常演奏确实不削**<br>⚠️ ⭐ 但探针**没有模拟"`pos` 瞬间跳满"** ⇒ ⭐ **抓不到那一拍的瞬时过载** ✅<br>⇒ ⭐ **正好解释"只在用力敲打时出现"** ✅<br><br>**⭐ 修法（⭐ 已定稿，⭐ 待回归跑完执行）**：⭐ 给 `vel_upd` 加**变化率限幅** —— ⭐ 挂在 **`sample_tick_i`** 上，⭐ **每音频采样拍最多变 ±1** ⇒ ⭐ 满量程 **255 拍 = 5.2 ms 平滑滑行**（⭐ 对人手**完全无感**）<br>⚠️ **⛔ 不能挂每 clk** —— ⭐ 那样 255 拍 = 5.1 µs，⭐ **仍比音频周期（20 kHz = 50 µs）快** ⇒ 🔴 **还是台阶** ✅<br>⚠️ **`calib` 的 `MAX_TRAVEL` 夹紧【挡不住这个】**（⭐ `pos_to_vel(1023)` 照样饱和 255）⇒ ⭐ **两处都要修** ✅<br><br>**⚠️ 一个未决问题（⭐ 下轮要查）**：⭐ `note_manager.v` 的 `ST_SUSTAIN` 注释自称 *"`adsr` 的 `ST_SUSTAIN` 会持续朝 `sustain_level` 收敛 ⇒ 改 `vel_r` ⇒ 音量立刻跟随"* —— ⚠️ **"持续收敛"与"立刻跟随"互相矛盾**<br>⭐ `adsr.v` 已确认 **`ST_DECAY` 是按 `DECAY_STEP` 斜坡**（`:104-108`），⚠️ 但 **`ST_SUSTAIN` 的行为未读到** ⇒ ⭐ **"力度改了 sustain 会不会跳"仍未定论**<br>📌 **但结论不变**：⭐ 加限幅**只会减少不连续** ⇒ ⭐ **无论跳还是滑都值得做** ✅<br><br>**🔴🔴 2026-09-28 晚：第一次实现【失败并已回退】—— 调试线索记在这里（⭐ 免得重踩）**<br>⭐ **改动**：⭐ `note_manager.v` 加 3 个模块级挂起寄存器（`vu_pend_r`/`vu_ax_pend_r`/`vu_val_pend_r`）+ 把 `vel_upd` 的循环体改成"每 `sample_tick_i` 最多 ±1" + 复位分支加 3 个寄存器<br>⭐ **结果**：⭐ `tb_note_manager` **两条判据都红**（⭐ 原判据 `:460` 期望"立即 == 240" ⇒ ⭐ 我改成"先递增、再收敛到 240"）<br>· 🔴 `FAIL: vel_update 起效（已开始向 240 递增）` ⇒ ⭐ **`vel_of(1)` 仍是 200** ⇒ ⭐ **力度【完全没变】** ⚠️<br>· 🔴 `FAIL: vel_update 收敛到 240（斜坡到位）` ⇒ ⭐ `run_ticks(60)` 后**仍是 200** ⚠️<br>⇒ ⭐ **说明挂起/应用逻辑【一次都没触发】** 🔴<br><br>**⭐ 已核实的 tb 事实（⭐ 下轮直接用）**：<br>· ⭐ `run_ticks(n)`（`tb:354-364`）：⭐ **`sample_tick` 高 1 clk，然后空 3 clk**，⭐ 循环 n 次 ⇒ ⭐ **n 个采样拍** ✅<br>· ⭐ `vel_of(v)`（`tb:240-243`）= `voice_velocity[v*VEL_W +: VEL_W]` ✅<br>· ⭐ `CLK_PER_SAMPLE = 64`（`tb:43`），⭐ 但 tb **手动**发 `sample_tick`（⛔ 不自动）<br>· ⭐ 原判据在 `:460`：⭐ **`vel_upd` 后 1 个 negedge 就检查** ⇒ ⚠️ 改契约后**必须**在 `run_ticks()` **之后**检查 ✅<br><br>**⭐ 下轮的两个待查点**：<br>① ⭐ **第一个 `chk` 必须在 `run_ticks(1)` 之后**（⭐ 否则必然读到旧值 ⇒ ⭐ 这一条**解释了 #1**）<br>② 🔴 **#2 说明应用逻辑真的没跑** ⇒ ⭐ 要查：⭐ (a) `gate_mask[i]` 是否为 1（⭐ `gate_r & ~retrig_low`）；⭐ (b) `axis_r[i] == vu_ax_pend_r` 是否匹配；⭐ (c) ⭐ `vu_pend_r` 的**置位/清零**是否在同一拍互相覆盖<br>📌 **建议做法**：⭐ **先只加挂起寄存器 + 打印**（⭐ 不改行为）⇒ ⭐ 确认 `vu_pend_r` 真的被置起 ⇒ ⭐ **再**加限幅 ✅（⭐ 一次只改一件事）<br><br>**🔴🔴 第二次尝试（⭐ "目标永不清零"版）—— 仍然失败，⭐ 也已回退**<br>⭐ **改动**：⭐ 修正了第一版的"应用后同拍清零"缺陷（⭐ 改成**目标锁存后永不清零**，⭐ 到达时 `else` 赋同值自然静止）⇒ ⭐ 编译过 ✅ ⚠️ **但 `tb_note_manager` 仍然 2 条红**<br>⇒ 🔴 **说明应用块【一次都没执行】** —— ⭐ **根因仍未找到** ⚠️<br>⭐ **已核实的边界条件（⭐ 下轮直接用）**：<br>· ⭐ `note_manager.v` 端口名确实是 **`sample_tick_i`** ✅<br>· ⭐ tb 手动发 `sample_tick`（⭐ `run_ticks(n)`：高 1 clk + 空 3 clk，⭐ 循环 n 次）✅<br>· ⭐ 我的块**在复位分支之后**（⭐ 与 `vel_upd` 原位一致）✅<br>· ⭐ 我**已把第一个 `chk` 移到 `run_ticks(1)` 之后** ⇒ ⚠️ **仍然红** ⇒ ⭐ **不是"检查太早"的问题** ✅<br><br>**⭐⭐ 下一步【必须】先加探针（⭐ ⛔ 不要再盲改）**：<br>⭐ 在应用块里加 `$display`，⭐ 逐条打印：<br>① ⭐ `vel_upd_valid_i` 有没有到（⭐ 置起拍）<br>② ⭐ `vu_pend_r` 有没有被置起<br>③ ⭐ `sample_tick_i` 有没有来<br>④ ⭐ `gate_mask[i]` / `axis_r[i] == vu_ax_pend_r` 有没有匹配<br>⇒ ⭐ **定位到具体哪一条断了，再动手** ✅<br>📌 **本项目的血泪纪律（`C83`）**：⭐ **探针假绿 / 盲改** —— ⭐ 判据红了**先确认它走到过目标路径** ✅ | RTL（`note_manager.v` / `adsr.v`） | 🔴 **待修（⭐ 机制闭合；⭐ 两次实现失败已回退；⭐ 下一步必须先加探针）**<br>✅✅ **2026-09-28 深夜【已修】（⭐ 第三次尝试成功）** —— ⭐ 详细收口见 `尖音修复-最终记录-20260928.md`<br>⭐ **探针一轮定位**（⭐ vs 前两轮盲改都失败）：`[VUDBG]` 打出 `valid` 到了、`apply` 每拍 +1 ✅ ⇒ ⭐ **真因是【旧判据在任何 `sample_tick` 之前就检查】** ⇒ ⭐ **RTL 一直是对的** ✅<br>⭐ 探针还纠正**我自己的两个错误假设**：⭐ 起始 `vel` 实测 **77**（⛔ 不是 200）· ⭐ 应用块**触发了**（⚠️ 是检查时机问题）<br>✅ **最终实现**：⭐ 模块级挂起寄存器 + ⭐ **目标锁存后【永不清零】** + ⭐ 每 `sample_tick_i` 最多 ±1 ⇒ ⭐ 满量程 255 拍 = **5.2 ms 平滑滑行**<br>✅ **非空洞性已证**：⭐ 变异掉限幅 ⇒ `tb_note_manager` **FAIL**；⭐ 有限幅 ⇒ **PASS** | RTL（`note_manager.v`） | ✅ **已修 + 已验证 + 非空洞性已证**<br>📌 **2026-09-29 补：⭐ 最终参数 = 【每音频采样拍最多 ±8】**（⭐ 满量程 255/8 = 32 拍 = **0.65 ms**）<br>· ⭐ **用户 2026-09-28 拍板选 ±8**（⭐ 折中：⭐ 削掉突变 + 力度跟随延迟几乎无感）<br>· ⚠️ **第一版是 ±1（5.2 ms）⇒ 回归 87/88**，⭐ 唯一失败 `tb_vel_pos_follow`（⭐ "按下更深 ⇒ 力度立即变大"两条红）<br>· ⭐ **±8 让 `tb_vel_pos_follow` 天然通过** ⇒ ⭐ **⛔ 不需要放松任何断言** ✅<br>· ⭐ **非空洞性**：⭐ 变异掉 ±8 限幅 ⇒ `tb_note_manager` **FAIL**；⭐ 有限幅 ⇒ **PASS** ✅<br><br>🔴🔴 **2026-09-29 更正（⭐ 离线代码核对，⭐ 决定性）：⭐ 本条的核心机制【不成立】—— 包络【不会】瞬间跳**<br>⭐ **证据（⭐ 代码级，⭐ 三处互证）**：<br>① ⭐ `adsr.v` 的 **`ST_SUSTAIN` 是【斜坡】**（⭐ 注释原文：*"Smooth a late velocity correction **instead of jumping**"*）<br>　· ⭐ **上升** = `env_level_o + ATTACK_STEP(669)`/拍 ⇒ ⭐ 满量程变化 **≈ 0.5 ms**<br>　· ⭐ **下降** = `env_level_o − DECAY_STEP(4)`/拍 ⇒ ⭐ **≈ 84 ms**<br>② ⭐ `envelope_bank.v` **没有覆盖**这三个参数（⭐ `ATTACK_STEP=669` / `DECAY_STEP=4` / `SUSTAIN_Q8=64` 与 `adsr.v` 默认值**完全一致**）<br>③ ⭐ `voice.v` 用的是**固定** `NOTE_VELOCITY=255`（⭐ 那条旧通路与 `vel_upd` 无关）⇒ ⭐ 真实通路 = `vel_r → envelope_bank → adsr.velocity_i → peak/sustain_level → env_level_o`（⭐ **斜坡**）<br>⇒ ⭐⭐ **结论**：⭐ **`vel_r` 猛跳 ⇒ 包络只按【斜坡】跟随，⛔ 不会瞬跳** ⇒ 🔴 **"瞬时过载 ⇒ 削波"这条链【断了】** ✅<br><br>📌 **同处还有一个【注释 ↔ 代码】矛盾（⭐ 本条原先只标"未定论"，⭐ 现已裁决）**：<br>⭐ `note_manager.v` 的 `ST_SUSTAIN` 收敛注释自称 *"`ST_SUSTAIN` 会持续**收敛** … ⇒ 改 `vel_r` ⇒ 音量【**立刻跟随**】"* —— 🔴 **"收敛"（斜坡）与"立刻跟随"互相矛盾**，⭐ **正确说法 = "按 `ATTACK_STEP`/`DECAY_STEP` 斜坡跟随"** ⇒ ⭐ **"立刻跟随"是错的** ✅<br><br>⚠️ **唯一真会瞬跳的地方（⭐ 与本条无关）**：⭐ `rtl/w3c/perc_env_bank.v` —— ⭐ 打击乐触发即 `level <= peak_r`（⭐ **设计如此**，⭐ 鼓要陡起音）⇒ ⚠️ 但 **`vel_upd` 只作用于键盘 voice** ⇒ ⭐ 与 `K-154` 无关 ✅<br><br>⇒ ⭐⭐ **对"又响又尖"的影响（⭐ 重要）**：<br>· 🔴 **削波假设**：⭐ 已被 `probe_headroom` 实测否定（⭐ 四组 `贴顶=0`）<br>· 🔴 **力度突变假设**：⭐ **本条现在也否定** ⇒ ⭐ **两条假设都没了** ⇒ 🔴 **"又响又尖"的根因【仍未找到】**<br>· ⇒ ⭐ **当前最可疑的线索 = 输入侧的 `raw` 跳变**（⭐ `K-153`）⇒ ⭐ **必须上板跑 `probe_q.py`** ✅<br>⚠️ **但 ±8 限幅【保留】**：⭐ 它减少不连续、⭐ 成本极低、⭐ 且**已通过全部判据**（⭐ 删掉要重新验证，⭐ 不划算）✅ |
| **K-153** | 🔴⭐ **`pos` 会越界到【标定行程的 2.6 倍】，且【span 标定必然失败】—— 两者是【同一个根因】**（⭐ 2026-09-28 用 `'Q'` 诊断上板实测 + 代码核对） | **⭐⭐ 实测数据（`'Q'` 诊断，⭐ 上板）**：<br>```
用力敲打：|Δpos| 峰值 2193（轴 1）· 典型 150~550
快速连按：|Δpos| 峰值  148 · 典型  20~110
```<br>⭐ 而 **`pos` 是 12 位（0..4095）· 满行程实测仅 744** ⇒ ⭐ **2193 = 满行程的 2.9 倍** ⇒ 🔴 **手指物理上不可能** ⇒ ⭐ **是读数/换算在跳** ✅<br><br>**🔎 根因链（⭐ 三步，全部代码级）**：<br>① ⭐ `calib.sv` `prod_r = (raw - zero) * gain >> 8` —— ⭐ 下溢**有**守卫（`raw > zero` 才乘）✅，⚠️ 但**上溢没有**<br>② ⭐ `calib.sv` `out_val = (shifted > FULL_EXT) ? FULL_CODE : ...` —— ⭐ **有限幅，但夹的是 `FULL = 4095`（输出满量程），⛔ 不是【该轴的标定行程 744】** ⇒ 🔴 **夹错了边界**<br>③ 🔴 **`gain` 停在默认值 `256`（= 1.0）** ⇒ ⭐ **`pos` 就是裸的 `raw − zero`** ⇒ ⭐ 而实测满行程只有 744（⭐ 若标定成功，满行程应映射到 4095）⇒ ⭐ **说明 span 标定【从未成功过】** ✅<br><br>**🔴 而 span 为什么失败 —— 与 `'Q'` 的数据同源**：<br>⭐ `calib_span` 要求"连续 N 帧变化 < `STABLE_TOL=48`" ⇒ ⚠️ **而 `raw` 一帧跳 150~500** ⇒ 🔴 **稳定判据永不满足 ⇒ 必然被拒** ✅<br>⭐ 另有 `calib.sv` `if (raw <= zero_r[cal_ch]) err <= 1`（满行程码 ≤ 零点 ⇒ 拒绝）<br><br>**⭐ 三个现象、一个根因**：<br>| 现象 | 同一根因 |<br>|---|---|<br>| ⭐ **span 标定总被拒** | ⭐ `raw` 在跳 ⇒ 稳定判据永不满足 |<br>| ⭐ **`pos` 越界到 2193** | ⭐ `gain` 未标定（=1.0）⇒ `pos` = 裸差值 ⇒ 一夹就是 4095 |<br>| ⭐ **尖音** | ⚠️ `pos` 猛冲 ⇒ 力度跟随流饱和 ⇒ 包络电平突变（⭐ **但见下方修正**） |<br><br>**🔴 重要修正（⭐ 2026-09-28 晚，⭐ 用户反问后）**：⭐ `pos_to_vel` 在 **`pos ≈ 744` 就饱和到 255** ⇒ ⭐ **`pos` 再越界也⛔不会更响** ⇒ ⭐ **所以"又响又尖"【不是】`pos` 越界造成的**（⭐ 见 `K-152`：那一类是**削波**）<br>⇒ ⭐ **`pos` 越界仍是个真 bug**（⭐ 它让 span 标定失败、让力度/事件流看到不可能的变化），⚠️ **但⛔ 不是"又响又尖"的元凶**<br><br>**⭐ 修法顺序（⭐ ⛔ 不是先夹 `pos`）**：<br>① ⭐ **先查清 `raw` 为什么跳**（⭐ ADC/SPI 读错 vs 霍尔/机械）⇒ ⭐ 用 `tools/probe_q.py`（⭐ 已加**按通道统计 `P` 的 spread**）<br>② ⭐ **修掉跳变** ⇒ ⭐ **span 就能标定成功** ⇒ `gain` 正确 ⇒ **`pos` 归一化到 4095** ⇒ ⭐ **一举修好三件**<br>③ ⭐ 最后给 `pos` 加限幅（⭐ 夹到**标定行程**）当**安全网**<br><br>**📌 诊断工具（⭐ 已落库）**：⭐ `rtl/top.v` 的 `DPOS_DIAG` 参数（⭐ **默认 0** ⇒ 不进综合）+ `tools/probe_q.py`（⭐ 发 `'P'` 读 `Q<轴号><dpos>` + 按通道统计原始码 spread） | RTL（`calib.sv` / `calib_span` / `adc_farm`） | 🟡 **部分已修 · 根因仍待定**<br>✅ **已修（2026-09-28）**：⭐ **`pos` 上界夹紧** —— `calib.sv` 新增 `parameter MAX_TRAVEL = 1023`，并把 `raw − zero` **先夹到 `min(MAX_TRAVEL, span_r[ch])`** 再乘增益<br>· ⭐ 判据：`tb_calib` 的 test① 改成 **"`raw=2048` ⇒ `out` 必须被夹到 `MAX_TRAVEL`"** ✅<br>· ⭐ **非空洞性已证明**（⭐ 手工变异：去掉夹紧 ⇒ **test① FAIL**；加回 ⇒ **PASS**）✅<br>· 🔴 **我第一版只夹 `span_r` 是错的** —— ⭐ `span_r` **只在 span 标定成功时才写** ⇒ ⭐ 那时 `gain` 已标定、`pos` 本来就被 `FULL` 夹住 ⇒ **空操作**；⭐ 而标定失败时 `span_r=0` ⇒ **完全不生效** ⇒ ⭐ 必须加**不依赖标定**的硬上界 ✅<br><br>🔴 **根因仍待定（⭐ 两个候选，⭐ 都只读查到了）**：<br>① ⭐⭐ **`mcp3208_driver.sv` 的 `adc_miso` 【未过 `sync_input`】** —— ⭐ 板外异步输入**直接进移位寄存器** ⇒ ⚠️ 违反本项目自己的 `K-62` 纪律<br>② ⭐⭐ **`SCLK_HZ = 1_000_000` 贴着 MCP3208 在 2.7 V 的上限** ⇒ ⭐ MISO 建立余量只有**半个位周期 500 ns**，⚠️ 再扣芯片 `tDO` + 板级延迟 ⇒ 🔴 **可能只剩几十 ns** ⇒ **偶发坏位** ⇒ ⭐ **偶发坏样本**（2170 → 1925/4095）⇒ ✅ **与 `Q` 实测完全对上**<br>③ ⚠️ 还可能是**霍尔/机械**（⭐ 用力时触点弹跳）⇒ ⭐ 需要 `probe_q.py` 的**按通道 spread** 才能分（⭐ 需用户上板）<br><br>⭐ **候选修法（⭐ 待根因确认后选）**：<br>· ⭐ **降 `SCLK_HZ` 1 MHz → 500 kHz**（⭐ 建立余量翻倍，⭐ 且 8 通道 × 48 µs = 384 µs < 500 µs 帧周期 ✅ 放得下）<br>· ⭐ **给 MISO 加 `sync_input`**（2 级 ⇒ 只延迟 40 ns，⭐ 对 1 µs 位周期无影响）<br>· ⭐ **`pos` 加中值滤波 / 变化率限幅**（⭐ 在数据源头挡）<br><br>✅⭐ **2026-09-29 已落地【软件侧兜底】（⭐ 但【默认关】）**：⭐ `rtl/drivers/calib.sv` 新增参数 **`RAW_MEDIAN_EN`**<br>· ⭐ **做法**：⭐ `raw` 过 **3 点中值**（⭐ `median(a,b,c) = a+b+c−min−max`，⭐ 纯算术、⛔ 无排序网络）⇒ ⭐ **滤掉【孤立】坏样本，⭐ 保留真实运动**（⭐ 真实运动至少影响 2 个连续样本）<br>· ⭐ **因果**（⭐ 窗口 = 本拍 ＋ 前 2 拍）⇒ ⭐ **不增加流水延迟** ✅<br>· ⭐⭐ **默认 `0`（关）** ⇒ ⭐ **与旧行为逐位一致**，⛔ **不影响任何既有判据 / 手感**（⭐ `tb_calib` 5 条原判据**全过**）<br>· ⭐ **验证**：⭐ `tb_calib` 新增 **3 条判据**，⭐ 用**同一激励喂两个实例**（`RAW_MEDIAN_EN=0/1`）⇒ ⭐ **A/B 互为反例 = 自证非空洞**（⭐ `PASS: calib T13 all 11 checks ok`）✅<br>· ⚠️ **何时打开**：⭐ **必须先上板跑 `probe_q.py` 量清 `raw` 的按通道 spread**（⭐ 根因未定之前⛔ 不擅自改用户能感觉到的行为）<br>· 📌 **为什么不做默认开**：⭐ 本项目纪律 = **改用户可见功能的时序/契约必须问用户**（⭐ 用户暂时不能上板 ⇒ ⭐ 先备好开关）✅<br>⚠️ **仍未解决**：⭐ `raw` 跳变的**根因**（⭐ 三条候选见下）—— ⭐ 中值只是**兜底**，⛔ 不是根因修复 ✅ |
| **K-155** | ⭐⭐⭐ **流水线改造里的"差一拍"只有【等值】延时判据能抓 —— 【范围】判据对它完全无感**（⭐ 2026-09-29 给限幅器加 1 级流水时实测） | **⭐⭐ 实测（⭐ 全部可复现）**：<br>① ⭐ `tb/w3b/tb_tdm_render_mixer.sv` 的延时判据**原来是范围**：`k >= POLY+3 && k <= POLY+8`（⭐ 名字却写 `fixed POLY_TARGET+7`）<br>② 🔴 **把 `valid_d[4]` 改回 `valid_d[3]`**（⭐ "加了流水却**忘了给 valid 加拍**"）⇒ 延时 `+8 → +7` ⇒ 🔴 **旧范围判据照样 PASS** ⚠️<br>③ ⭐ **为什么【值类】判据也抓不到**（⭐ 关键实测）：⭐ **数据比 `valid` 早 4 拍到位** —— `t_last_change = 35` · `t_valid = 39` ⇒ ⭐ **差一拍取到的仍是正确值**（⭐ 单侧安全：⭐ valid 晚于数据无害）<br>⇒ ⭐ **结论**：⭐ 这一类改动**只有等值判据能守**；⚠️ 值类/相位类判据**只能守"不能太早"**，⛔ 守不住"差一拍" ✅<br><br>**⭐ 修法（⭐ 已落地）**：<br>· ⭐ 期望值抽成 **`localparam LAT_EXPECT = POLY + 8`** ⇒ ⭐ 改流水**只改这一行**（⭐ 消除"每次同步数字"的代价）<br>· ⭐ 断言改成**等值** `k == LAT_EXPECT`<br>· ⭐ **另加一条【与深度无关】的判据**：⭐ `dry_valid` ⛔ 不得早于 `dry_sample` 的最后一次变化（`t_valid >= t_last`）⇒ ⭐ 永久有效，⛔ 不随流水改<br><br>**⭐⭐ 非空洞性（⭐ 三条都实测过）**：<br>· ⭐ **忘加宽 `valid_d`**（⭐ 声明留 `[3:0]`）⇒ 🔴 **14 条 FAIL**（⭐ 输出 X）<br>· ⭐ **`valid_d[4] → valid_d[3]`** ⇒ 🔴 **等值判据 FAIL**（⭐ `+7 ≠ +8`）· ⚠️ 旧范围判据 **PASS** ⇒ ⭐ 漏洞已复现<br>· ⭐ **valid 提前 6 拍【移动】发出**（⭐ 每帧仍只 1 个脉冲，⭐ 排除多脉冲干扰）⇒ 🔴 **同拍判据 FAIL**（`t_valid=33 < t_last=35`）<br><br>📌 **配套留痕**：⭐ `files/20-代码/文档取代关系索引.md` §一·补 **第 2 条** ✅ | RTL + 验收 tb | ⭐ **所有流水线改造的"valid / 数据同拍"契约** | ✅ **已修 + 已证（2026-09-29）**<br>📌 **同族**：`K-109`（valid 与载荷差一拍）· `C88`（**名字写等值、实际是范围**）<br>📌 **可复用判据**：⭐ **"两级流水之间隔了几拍"必须用【等值】判据守** ✅ |
| **K-156** | ⭐⭐⭐ **非空洞性证明脚本【自己】会静默失效 —— 一个脚本三个独立缺陷叠加，⭐ 它从未产生过任何证明**（⭐ 2026-09-29 实测） | **⭐⭐ 现场**：⭐ 想给 `K-153`/`K-154` 补变异体，⭐ 于是**真跑了一次** `sim/check_met_btn_nonempty.ps1` ⇒ 🔴 **跑不起来** ⇒ ⭐ 逐层挖出**三个互不相关的缺陷**：<br><br>| # | 🔴 缺陷 | ⭐ 症状 | ⭐ 根因 |<br>|---|---|---|---|<br>| **1** | ⭐ 3 行**中文注释** ＋ **无 UTF-8 BOM** | ⭐ `意外的标记 ")"` | 🔴 **`C72`：PS 5.1 按 GBK 解码 ⇒ 中文吃掉行尾换行** ⇒ ⭐ **下一行 `$rtlBase = @(Get-ChildItem ...)` 被并入注释** ⇒ ⭐ 再下一行的 `)` 变孤立 ✅<br>⚠️ 文件头**自称** *"pure ASCII on purpose"* ⇒ ⭐ **本意是纯 ASCII，中文是意外** |<br>| **2** | 🔴 **排除逻辑写错**：`$rtlBase` 存的是**字符串**，⭐ 却写 `$_.FullName -ne $mfAbs` ⇒ ⭐ `$_.FullName` 恒 `$null` ⇒ **一个都没排除** | ⭐ `error: 'top' has already been declared` | ⭐ 变异副本与原文件**同时进 `iverilog`** ⇒ 🔴 **每次都在编译步就死** ✅<br>📌 **干跑实测**：旧写法剩余 **50** · 新写法剩余 **49**（⭐ 恰好排除 1 个）✅ |<br>| **3** | ⭐ `MUT8` **锚点失效**（⭐ 找 `8'd1`，⭐ 代码已是 `8'd8`） | ⭐ `SKIP ... anchor is stale` ⇒ `exit 1` | ⚠️ 2026-09-28 参数从 ±1 定成 **±8** ⇒ ⭐ **锚点没跟着改** ✅ |<br><br>⇒ ⭐⭐ **核心教训**：🔴 **"脚本在那儿" ⛔ ≠ "它真的在跑"** —— ⭐ **非空洞性证明本身也会静默失效** ✅<br>📌 ⭐ **同族**：`L74`（证据时效）· `C88`（名字写等值、实际是范围）· `C83`（探针假绿）· `K-38`（`.ps1` 编码）<br>⭐ **机械判据（⭐ 新增纪律）**：⭐ **每次改完 `rtl/` 就要【真跑一次】变异脚本**，⛔ 不能靠"上次它是绿的" ✅<br>⭐ **附加教训**：⭐ **文档里的"待办"也会错** —— ⭐ 我早先据"脚本写死只变异 `top.v`"写下待办，⭐ 实际它**早已支持 `file` 字段** ⇒ ⚠️ **写待办前要先读实现** ✅ | `sim/check_met_btn_nonempty.ps1` ＋ `rtl/` | ⭐ **`K-153`/`K-154` 的非空洞性证明**（⭐ 一直是死的） | ✅ **已修全部三处**（2026-09-29）<br>⭐ **改动**：① 3 行中文注释改英文 ⇒ **全文件纯 ASCII** ② `$_ -ne $mfAbs` ③ `MUT8` 锚点 `8'd1` → `8'd8`<br>⭐ **新增** `MUT9`（`valid_d` 忘加宽）/ `MUT10`（差一拍）/ `MUT11`（valid 提前 6 拍）<br>⭐ **11 个锚点已静态核对**：全部**有效且唯一** ✅<br>⭐ **且已真跑通过**（⭐ 见 `sim/evidence/check_nonempty_run2.log`）✅ |
| **K-157** | ⭐⭐⭐⭐ **`reg [...] mem [0:N]` 用【异步读】⇒ Gowin 推不出 BSRAM、改推 DFF ⇒ 超过器件 DFF 上限 ⇒ 🔴 综合【整个失败】，而仿真 100% 全绿**（⭐ 2026-09-29 首次 PnR 实测） | **⭐⭐ 现场**：<br>⭐ 新写的 `rtl/w3c/looper.v` 里事件存储是 `reg [65:0] mem [0:2047]`（⭐ **2048 × 66 bit**）<br>⭐ **写侧**：⭐ `mem[cnt_r] <= {...};`（⭐ 单写口 ＋ 寄存地址）✅<br>🔴 **读侧**：⭐ `wire [EW-1:0] e_word = mem[rd_ptr_r];`（⭐ **异步读**）<br>⇒ 🔴 Gowin 报：<br>```<br>ERROR (IF0008) : The number(135168) of DFF used to infer "mem"<br>                 exceeds the resource limit(60780) of current device<br>```<br>⇒ ⭐⭐ **注意那个数字**：⭐ `135168` **正好 = 2048 × 66** ⇒ ⭐ 它**试图用 DFF 搭出整块存储** ⚠️<br>⚠️ 而**仿真侧**：⭐ `tb_looper` **9 条判据全过** · ⭐ `iverilog -g2012 -Wall` **零 error 零 warning** ✅<br>⇒ 🔴 **"仿真全绿" ⛔ 完全掩盖了它**（⭐ `K-91` / `K-87` 同族）<br><br>**⭐⭐ 根因**：⭐ **Gowin BSRAM 的读输出【必须寄存】** ⇒ ⭐ **异步读无法映射到 BSRAM** ⇒ ⭐ 只能退化成 DFF ✅<br><br>**✅ 修法**：⭐ **把读出的字打一拍**（⭐ 标准同步读）：<br>```<br>reg [EW-1:0] e_word_r;<br>always @(posedge clk_i) e_word_r <= mem[rd_ptr_r];<br>```<br>⚠️ **代价**：⭐ 每吐一条事件要 **2 拍**（⭐ 1 拍推进指针 ＋ 1 拍等数据回来）⇒ ⭐ **必须配一个 `rd_adv_r` 标志**，⭐ 把"**数据还没跟上**"那一拍**也当作"本 tick 没排空"**（⭐ 否则**同拍剩下的会被跳过**）⚠️<br><br>📌 **本项目的三道防线各自起了作用**（⭐ 值得记）：<br>① ⭐ **PnR**（⭐ 唯一的"真综合"验证）⇒ ⭐ **抓到了** ✅<br>② ⭐ **`U-31` 产物新鲜度守卫** ⇒ ⭐ **拒绝发布上一版的旧时序证据**（⭐ 否则会拿旧 Fmax 当新结果）✅<br>③ ⚠️ **仿真 / 编译自检** ⇒ 🔴 **完全没抓到**（⭐ 所以它**不能**当综合证据）<br><br>⭐ **机械判据（⭐ 可复用）**：⭐ **只要 RTL 里出现 `reg [...] mem [0:N]`，就先问一句"读是同步的吗？"** ——<br>⭐ **异步读 ⇒ 推不出 BSRAM**（⭐ 除非整块能塞进 DFF，⭐ 而 2048×66 显然不能）✅ | RTL（`rtl/w3c/looper.v`） | ⭐ **任何"用 `reg` 数组做存储"的模块** | ✅ **已修 + 已证**（2026-09-29）<br>⭐ 修后 `tb_looper` **9 条判据仍全过**，⭐ 且**偏移逐条不变**（⭐ 说明 tick 级时序**没受影响**）✅<br>📌 **同族**：`K-91`（SV 构造 ⇒ 模块被**静默丢弃**）· `K-87`（"看起来验过了"）· `U-31`（产物新鲜度） |
| **K-158** | ⭐⭐⭐ **looper 回放中按 `C` 清空 ⇒ 【挂音】永远不停**（⭐ 2026-09-29 上板实测 ⇒ ✅ **已修**） | **⭐⭐ 现象（用户原话）**：*"loop 在回放的时候按 c 清空的话，会一直有当前播放的那个音的挂音，没办法消失"* ✅<br><br>**🔴 根因（代码级）**：⭐ `rtl/w3c/looper.v` 的 `clear` 分支**直接** `state <= ST_IDLE` ＋ 清 `cnt_r`/`rd_ptr_r`<br>⇒ ⭐ **那一拍正在响的 loop 音【永远收不到 `note_off`】** ⇒ ⭐ `note_manager` 的 `gate_r` **永久为 1** ⇒ 🔴 **挂音** ✅<br>📌 ⭐ **讽刺的是**：⭐ `ST_CLOSE`（**停录时逐轴补发 `note_off`**）**早就写好了** —— ⚠️ 只是 `clear` **没走它** ✅<br><br>**✅ 修法**：⭐ 新增 `play_active_r`（16 位：⭐ 重放 `note_on` 置位 · `note_off` 清零）＋ ⭐ **`ST_LCLOSE` 状态逐轴补发**（⭐ 复用 `ST_CLOSE` 的扫描）⇒ ⭐ `clr_after_r` 决定补完是否清空 ✅<br>⚠️ **同一个缺陷类**：⭐ **"停播"（`play_en` 落沿）也会挂音** ⇒ ⭐ 一并走 `ST_LCLOSE`（⭐ `clr_after_r = 0`，⭐ 只补发 ⛔ 不清空）✅<br>⚠️ `state` 从 **2 位加宽到 3 位**（⭐ 4 个码已用满）✅<br><br>**⭐ 判据**：⭐ `tb_looper` 判据⑩ —— ⭐ 录一个**很长的音** ⇒ 起播 ⇒ ⭐ **在音还在响时（tick 10）发 `clear`** ⇒ ⭐ **输出里必须出现过该轴的 `note_off`** ✅<br>**⭐ 非空洞性**：⭐ 把 `clear` 改回旧写法 ⇒ ⭐ **判据⑩ 变红，且只有它红** ✅ | RTL（`rtl/w3c/looper.v`） | ⭐ 任何"带状态的重放 / 序列器" | ✅ **已修 + 已证**（2026-09-29）<br>⭐ 既有 9 条判据仍全过 ✅ |
| **K-159** | ⭐⭐⭐⭐⭐ **"位置式力度"同时改变了【音色】** —— ⭐ 按到底 ⇒ **纯三角波** ⇒ 用户听到"电子音"（⭐ 2026-09-29 上板实测 ⇒ ✅ **已修**） | **⭐⭐ 现象（用户原话）**：*"按到靠近底部时，偶尔会出现不同的音色，稍微电子一点，但是听起来没有削顶，并且会随着底音同样进行打拍的音量起伏"* ＋ *"幅度可能不完全一样，我的意思是**变化趋势是相同的**"* ✅<br><br>**🔴 根因（代码级 100% 确认）**：<br>`note_manager.v` 的 `voice_velocity_o = vel_r[g]`<br>`　├─→ envelope_bank   ⇒ ⭐ 音量（⭐ 用户要的 ✅）`<br>`　└─→ oscillator_bank ⇒ ⭐ soft/hard 波表插值 = 【音色】（⚠️ 副作用）`<br>`oscillator_bank.v` 的 `// velocity=0 picks soft; velocity=255 picks hard`<br>`oscillator_bank.v` 的 `rom_dout = rom_soft + (rom_hard - rom_soft) × vel/256`<br>⇒ ⭐ `vel_upd`（位置式力度）把 `vel_r` 推到 **255** ⇒ 🔴 **按到底变成纯 `rom_hard` = 三角波** ✅<br>⭐ 而 `rom_soft` = **正弦** ⇒ ⭐ **音色从正弦变三角** = "电子音" ✅<br><br>**⭐⭐ 实测谱形（⭐ 决定性证据）**：<br>⭐ 捕获参数：⭐ **100 ms 窗口 / 100 kHz 采样**（⭐ 分辨率 10 Hz）· C3 键<br>| ⭐ 谐波 | ⭐ 幅度 | ⭐ 判读 |<br>|---|---|---|<br>| h1 (132 Hz) | 0 dB | 基频 |<br>| h2 (264) | −22.5 dB | 偶次**弱** |<br>| **h3 (396)** | **−18.9 dB** | ⭐⭐ 三角波理论值 **1/9 = −19.1 dB** ⇒ ⭐ **完全吻合** |<br>| **h4 (528)** | **−46.5 dB** | ⭐⭐ **深零点**（三角波偶次为 0）|<br>| h5 (660) | −21.8 dB | 奇次 |<br>| h7 (924) | −32.2 dB | 奇次 |<br>⇒ ⭐⭐ **结论：就是三角波** ✅（⭐ 锯齿应单调下降、方波 h3 应为 −9.5 dB ⇒ ⭐ 都不是）✅<br><br>**📌 为什么"幅度趋势相同"**：⭐ 正弦与三角波的**峰值幅度相同** ⇒ ⭐ 只是**谐波结构**变了 ⇒ ⭐ 与用户描述**完全一致** ✅<br><br>**📌 为什么 looper 回放听不到**：⭐ looper **不录 `vel_upd`**（⭐ 见 `K-160`）⇒ ⭐ 回放的 `vel` = **起音力度**（低）⇒ 正弦 ⇒ ⛔ 没有电子音 ✅<br><br>**✅ 修法（⭐ 用户裁定 2026-09-29）**：⭐ **"不应该改变音色"** ⇒ ⭐ `oscillator_bank` 加 `parameter VEL_TIMBRE_BLEND`，⭐ **默认 0** ⇒ ⭐ `rom_dout = rom_soft`（⭐ 音色**只由 `timbre` 决定**）✅<br>⭐ 保留参数的理由：⭐ ① 可回退 ✅ ② ⭐ **用户说"后续还会改波表"** ⇒ ⭐ 改波表时**不用再动这一路** ✅<br>⭐ **附带好处**：⭐ 编译期常量 ⇒ ⭐ **混合乘法器被综合器整块折叠掉** ✅<br><br>**⭐ 判据**：⭐ `tb_oscillator_bank` 判据⑨ —— ⭐ **同一 timbre、同一相位下，`velocity = 0` 与 `255` 的样本必须【逐位相同】** ✅<br>**⭐ 非空洞性**：⭐ `VEL_TIMBRE_BLEND` 改回 `1` ⇒ ⭐ **判据⑨ 变红，且只有它红** ✅ | RTL（`rtl/w3b/oscillator_bank.v`）· 设计耦合 | ⭐ **任何"力度既控音量又控音色"的合成器** | ✅ **已修 + 已证**（2026-09-29）<br>📌 ⭐ **同族**：⭐ `L92`（仿真全绿 ≠ 能综合）· ⭐ 本条是"**功能全绿 ≠ 听感对**" ✅ |
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
