hokuu1102/Gowin2026-PolySynth/files/20-代码/待用户裁定问题清单-20260930.md

# ❓ 待用户裁定 —— 问题清单（2026-09-30 夜整理）

> **用途**：⭐ **把今晚所有"需要用户才能定"的问题一次收齐** ⇒
> 　　⛔ **今晚的工作不再被这些问题阻塞**（⭐ 能绕开的都绕开，绕不开的标注出来）。
> **状态**：⭐ **等用户回复**（⚠️ 回复前，本清单之外的活继续自主推进）
> **工作目录**：`C:\Users\hokuu\Desktop\FPGA\FPGA2026-esp32`

---

## 〇、⭐⭐ 速览（⭐ 按"急不急"排序）

| # | 问题 | ⭐ 紧急度 | ⚠️ 不答的后果 |
|---|---|---|---|
| **Q1** | ⭐ **模式 B 到底还要不要？**（起播架构） | 🔴 **高** | ⚠️ 挡住 CMD 的"起播"命令；⭐ 也挡住最终验收 |
| **Q2** | ⭐ **上行载荷格式是什么？** | 🔴 **高** | ⚠️ 挡住"丢整帧"策略；⭐ 但**不挡透明缓冲**（✅ 已实现） |
| **Q3** | 🔴 **「不做反向通道」⇔「要回传事件」怎么裁定？** | 🔴 **高** | ⚠️ 挡住反压设计 |
| **Q4** | ⭐ **FPGA 侧会不会【持续超发】？** | ⚠️ 中 | ⚠️ 决定上行环容量够不够 |
| **Q5** | ⭐ **PC 侧还有限速能力吗？** | ⚠️ 中 | ⚠️ 路线 A（纯透传）的前提 |
| **Q6** | ⚠️ **`uart_tx.v` 做不做？** | ✅ **已裁定：做了** | 🔴🔴 **2026-10-01 修正：⚠️ 原文写「不做 ⇒ 反向通路永远收不到东西」⇒ 【已作废】** —— ⭐ `rtl/w3c/uart_tx.v` 已存在且已在 `top.v:943` 例化（⭐ `.BAUD_DIV(100)` = 500 k，⭐ 另补 `uart_tx_fifo` @ `:928`），⭐ 且 **FPGA→ESP32→BLE→PC 2000 字节 round-trip 逐字节一致**（`esp32/evidence/反向通路验收-ESP32侧-20260930.md`） |
| **Q7** | ⭐ **`play_seq` 何时在 `top.v` 例化？** | ⚠️ 中 | 🔴 不出声 |
| **Q8** | ⭐ **接通 2MB → 16MB 映像头，认不认？** | ✅ **已完成** | 🔴🔴 **2026-10-01 修正：⚠️ 原文写「⚠️ 浪费 14 MB flash」⇒ 【已作废】** —— ⭐ 实测 `esp32/ble/sdkconfig.defaults:40-41` 已是 `CONFIG_ESPTOOLPY_FLASHSIZE_16MB=y` / `"16MB"`（⭐ 分区表未动） |
| **Q9** | ⚠️ **串口屏什么时候接？** | ✅ **已接并验收** | 🔴🔴 **2026-10-01 修正：⚠️ 原文写「⚠️ HMI 397 行代码**从未真机跑过**」⇒ 【已作废】** —— ⭐ 屏已接 + 5V，HMI 全链路验收通过（`esp32/evidence/串口屏HMI验收报告-20261001.md`） |
| **Q10** | ⭐ **B 子集等 2 个提交，要不要 push？** | 🔵 低 | ⚠️ 不影响今晚 |

---

## 一、🔴 Q1 —— 模式 B 到底还要不要？（⭐ 最高优先）

**⭐ 背景**：⭐ 存在一个**架构互斥**，⛔ 文档两侧各写各的、没人点破：

| 侧 | ⭐ 主张 |
|---|---|
| FPGA 侧 | ⭐ **方案③：上板手动按键起播**（`FPGA侧答复:24`：「⛔ 你那边不用改固件」） |
| ESP32 侧 | ⭐ **模式 B：ESP32 自己按谱子时间放水**（`pool.c:9`） |

🔴 **两者都要"自己决定什么时候放"** ⇒ ⚠️ 没有交集。

**⚠️ 更关键的技术障碍**：⭐ `pool_start()` 把"谱面第 0 拍"锚在
**ESP32 的 `esp_timer`** 上（🔴🔴 **2026-10-01 修正：⚠️ 原文写 `pool.c:412-413` ⇒ 【该处不存在这个符号】**；⭐ 实测锚点在 `pool.c:461-462`）⇒
🔴 **若起播键在 FPGA，两边时间基准【无法对齐】** —— ⚠️ 而 `pool.c:22` 明确「不做反向通道」⇒ **无解**。

**⭐ 需要你定**：

| 选项 | ⭐ 含义 | ⚠️ 代价 |
|---|---|---|
| **A** | ⭐ **认方案③**：FPGA 自己缓冲自己放；ESP32 只当"无线 U 盘" | 🔴 需 PC 侧实时限速（⭐ FPGA 缓冲 8 KB ≈ 92 ms） |
| **B** | ⭐ **走模式 B**：起播键移到 ESP32 + 新增起播命令 | 🔴 **= 方案②，需重谈协议** |

⭐ **详细分析**：`files/20-代码/矛盾裁定单-方案3与模式B-20260930.md`

---

## 二、🔴 Q2 —— 上行载荷格式是什么？

**⭐ 现状**：⭐ **一个字节都没定**。
⭐ 相关文档只说过「若将来要做上行，建议也遵守 9N」（`ESP32侧串口命令格式:198`）。

**⭐ 需要你/FPGA 侧定**：
1. ⭐ 上行是**裸字节流**，还是**带帧头**？
2. ⭐ 要不要 **9N 对齐**？（⭐ 注：上行是**真 UART**，字节边界天然保留 ⇒ ⭐ **9N 不是必需的**）
3. ⭐ 内容是**演奏事件**、**状态**、还是**两者混**？

⭐⭐ **重要**：⭐ **本题不阻塞今晚** ——
⭐ 已实现的 `up_ring` 是**透明字节流缓冲**（⛔ 不解释内容）⇒ ⭐ **与格式无关**。

---

## 三、🔴 Q3 —— 「不做反向通道」⇔「要回传音乐事件」冲突

**⭐ 背景**：
- ⭐ `ESP32通路交接文档 §4.4` 拍板「**先不做反向通道**」
- ⭐ 而你现在的需求是「**FPGA 回传音乐事件，通过 ESP32 蓝牙回传 PC**」

🔴 **这两条直接冲突**（⭐ 反压/流控就是"反向通道"的一部分）。

**⭐ 需要你定**：
1. ⭐ 「不做反向通道」这条**还算数吗**？（⭐ 还是仅指"不做流控"？）
2. ⭐ 若**只做数据回传、不做流控** ⇒ ⚠️ **上行满了只能丢**（⭐ 已实现"拒绝新的 + 记账"）
3. ⭐ 若要**流控** ⇒ 🔴 需要**新增一条 ESP32 → FPGA 的"忙"信号**

---

## 四、⭐ Q4 —— FPGA 侧会不会【持续超发】？

**⭐ 为什么问**：⭐ 决定上行环 **160 KB 够不够**。

| 情形 | ⭐ 160 KB 能撑多久 |
|---|---|
| ⭐ 按音乐节拍（~626 B/s） | ⭐ **~262 秒** ✅ |
| 🔴 持续满速（50 KB/s） | 🔴 **~3.3 秒** ⚠️ |

**⭐ 需要 FPGA 侧回答**：⭐ **回传是按节拍发，还是一口气倾泻？**

⚠️ **注意**：⭐ 本项**不阻塞今晚** —— ⭐ 缓冲 + 记账已实现，⭐ 满了会 `u_drop` 增长（✅ 可见）。

---

## 五、⭐ Q5 —— PC 侧还有限速能力吗？

**⭐ 为什么问**：⭐ 这是**路线 A（纯透传）的前提** ——
⚠️ PC 不限速 ⇒ 🔴 FPGA 的 8 KB 缓冲 **92 ms 就灌满**。

**⭐ 现状**：⭐ `tools/evt2uart.py` **本来就是实时限速的**（`ESP32侧接续准备:175`）。
⚠️ 但它指向的是**蓝牙 SPP 配对后的 COM 口**
⇒ ⚠️ **要改到 BLE 通路**（⭐ 我已有 `send_frames_ble.py` 的 `bleak` 直连可用）。

**⭐ 需要你确认**：⭐ 是否接受"**PC 侧限速 + ESP32 透传**"这条路？

---

## 六、⚠️ Q6 —— `uart_tx.v` 做不做？

**⭐ 现状**：🔴 **不存在** ⇒ ⭐ **ESP32 现在收不到 FPGA 的任何回话**。

⭐ 这条**归 FPGA 线**（⭐ 我们改不了 `rtl/`）。

**⭐ 需要 FPGA 侧回答**：⭐ 做不做？什么时候？

---

## 七、⭐ Q7 —— `play_seq` 何时在 `top.v` 例化？

⚠️ **注**：⭐ 你之前已核实过「`SCORE_UART_ENABLE=1`，曲谱链**已接通**」
⇒ ⭐ **本项可能已不成立**（⭐ 我看到的 `FPGA2026-esp32` 里的 `rtl/` 是**旧快照**）
⭐ **建议**：⭐ 以 `FPGA2026` 主仓库为准 ⇒ ⚠️ **若已接通，本项可划掉**。

---

## 八、🔵 Q8 —— 映像头 2MB → 16MB

**⭐ 已核实**（⭐ 实机查询）：

```
esptool flash_id  =>  Detected flash size: 16MB
```

⚠️ 而 `sdkconfig` 里写的是 **`CONFIG_ESPTOOLPY_FLASHSIZE="2MB"`** ⇒
🔵 **当前不阻塞**（app 仅 0.79 MB），⚠️ **但将来放曲谱/字库会浪费 14 MB**。

**⭐ 需要你定**：⭐ 现在改吗？（⚠️ 改 flash size 会**影响分区表**，⭐ 需重新验证）

---

## 九、⚠️ Q9 —— 串口屏什么时候接？

🔴🔴 **2026-10-01 修正：⚠️ 原文写「屏至今未接 ⇒ HMI 397 行代码从未在真机跑过」⇒ 【已作废】** —— ⭐ **屏已接上并全链路验收通过**（⭐ 屏上 6 栏全部跟着状态变；`esp32/evidence/串口屏HMI验收报告-20261001.md`）。
⭐ `hmi: no 0x88 ACK` 是"没接屏"的**正常降级**（⛔ 不是故障）。

**⭐ 需要你**：⭐ 接屏 + **5V 供电**（🔴 VCC 必须 5 V，⛔ 3.3 V 不亮）。
⚠️ 另需（🔴🔴 **2026-10-01 修正：⚠️ 原文「`TX→GPIO5`、`RX→GPIO4`」**没写清是**哪一侧**的 TX/RX ⇒ ⚠️ **极易读反**）：⭐ **ESP32 `GPIO4`(TX) → 屏 `RX`** · ⭐ **ESP32 `GPIO5`(RX) ← 屏 `TX`** · `115200` 8N1（⭐ 与 `esp32/ble/main/ble_config.h:451-452` 的 `BLE_PIN_HMI_TX 4` / `BLE_PIN_HMI_RX 5` 一致）。

---

## 十、⭐ Q10 —— 要不要 push？

**⭐ 现状**：⭐ 本地**领先远端若干提交**（⚠️ 具体数**以 `git status -sb` 为准**，⛔ 别记死）。

**⭐ 需要你同意**：⭐ push 必须先经你点头（⭐ 这是铁律）。

---

## ⭐⭐ 十一、今晚【不因这些问题停手】（⭐ 明确说清）

⭐ **能绕开的都绕开了**：

| 问题 | ⭐ 绕开方式 |
|---|---|
| **Q1**（起播架构） | ⭐ CMD 只做 `0x01`/`0x02`，⛔ **不做起播** |
| **Q2**（上行格式） | ⭐ `up_ring` 做**透明缓冲**（⛔ 不解释内容） |
| **Q3**（反向通道） | ⭐ 已实现"拒绝新的 + 记账"，⛔ 不依赖流控 |
| **Q4**（超发） | ⭐ 容量 160 KB + `u_drop` 可观测 |
| **Q6/Q7**（FPGA 侧） | ⭐ 不碰 `rtl/` |
| **Q9**（屏） | ⭐ 需要硬件，⭐ 跳过 |

⇒ ⭐ **今晚可做的（任务 2~6）都不受影响** ⇒ ✅ **继续自主推进**。

---

## 附 · 关联文档（⭐ 各问题的完整分析）

| 想看什么 | 去哪 |
|---|---|
| ⭐ **Q1 完整分析** | `files/20-代码/矛盾裁定单-方案3与模式B-20260930.md` |
| ⭐ **Q2/Q3/Q4/Q6 完整分析** | `files/20-代码/反向通路对接单-给FPGA侧-20260930.md` §三 |
| ⭐ **Q2/Q4 的容量与策略论证** | `files/20-代码/上行通路缓冲设计-20260930.md` §十一 |
| ⭐ 今晚在做什么 | `files/20-代码/今晚任务书-20260930.md` |
