hokuu1102/Gowin2026-PolySynth/files/20-代码/LED指引-实现计划清单-20261014.md

# LED 演奏指引 —— 实现计划清单（2026-10-14）

> **范围**：⭐ **只写 LED 这条线**（⛔ 不含效果器/频谱/其他评分项）
> **目标**：⭐ **指引模式**（只亮灯 ＋ 节拍器/鼓机照响，⛔ 音符不出声）
> ＋ ⭐ **提前亮**（可能提前一拍）＋ ⭐ **写码阶段尽量省资源** ✅
> **依据**：⭐ 赛题 B3 *"基于 FPGA 逻辑实时生成可视化：**LED 演奏指引**…"*
> ＋ ⭐ B4 *"脱机演奏 **LED 曲目指引**"* ✅

---

## 一、⭐ 需求（原样照抄）

> **B3** *"延迟压到 **≤5ms 且确定性无抖动**；基于 FPGA 逻辑实时生成可视化：**LED 演奏指引、李萨如图形、实时频谱、波形显示**"*

> **B4** *"脱机演奏 **LED 曲目指引**；**可**搭载蓝牙与手机 App（在线曲谱下载、键位自定义、演奏录音回传）"*

> **E4（反推硬约束）** ⭐ 音频与视觉效果的**"生成"⛔ 绝不能用软核/MCU**；⭐ **专用状态机不算软核** ✅

⭐ **用户口径（2026-10-14）**：
> *"加一个指引模式：只有 led 指引（可能提前一拍亮起？）和谱面对应的节拍器/鼓机，没有声音。
> 也就是说灌谱分成两种：一种是上面说的指引，另一种就是普通的演奏模式：
> 什么时候发声，led 就亮对应的轴。"*

---

## 二、⭐ 现状（⭐ 已做的 —— ⛔ 不重复造）

| 环节 | 模块 | 状态 | 说明 |
|---|---|---|---|
| **事件 → 位图** | `rtl/w3c/guide_lamp.v` | ✅ **已接**（2026-10-11） | 64 bit 事件 ⇒ **16 位 one-hot**（"该按哪个键"） |
| **消隐** | `guide_lamp.guide_vis_o` | ✅ | ⭐ = **该按 且尚未按下**（`P0-28`）⇒ ⭐ 能分清"该按的/正在响的" ✅ |
| **灯规则** | `rtl/w3c/led_data.v` | ✅ **已接** | 按下 ⇒ **常亮**；该按未按 ⇒ **闪烁**（`blink_i`） |
| **控制板灯驱动** | `tlc5916_bank` | ✅ | 16 键灯 ＋ 8 状态灯（24 位图案） |
| **WS2812 状态灯** | `led_indicator` ＋ `ws2812_driver` | ✅ | ⚠️ **7 颗状态灯，⛔ 不是键位指引**（另一条链） |
| ⭐ **普通演奏模式** | — | ✅ **就是现状** | *"什么时候发声，led 就亮对应的轴"* ✅ |
| 🔴 **指引模式（不出声）** | — | ⛔ **未做** | ⭐ **本次要做的** |
| 🔴 **提前亮** | — | ⛔ **未做** | ⭐ **本次要做的** |

⭐ **两条链别搞混**：
```
⭐ 键位指引（你要的）：guide_lamp ⇒ led_data ⇒ tlc5916_bank ⇒ 控制板 16 键灯 ✅
⭐ 状态灯（另一条）  ：led_indicator ⇒ ws2812_driver ⇒ 控制板 7 颗灯带 ✅
```

---

## 三、⭐ 要做的三块

### 🟢 L1 · 指引模式（⭐ 改动最小，优先做）

| 项 | 内容 |
|---|---|
| **语义** | ⭐ 灌谱时：⭐ **只亮 LED ＋ 谱面对应的节拍器/鼓机照响**，🔴 **音符不出声** ✅ |
| **静音点** | 🔴 **`seq_arb.score_valid_i`**（`top.v:4991` 附近） |
| **为什么正好在这里** | ⭐ `guide_lamp` 读的是**它上游**的 `ps_note_valid` ⇒ ⭐ **闸住进 `seq_arb` 那一路，LED 照常工作** ✅ |
| **节拍器/鼓机** | ⭐ 走**源 B**，⛔ 完全不受影响 ⇒ ⭐ 正好是你要的"**节拍器/鼓机照响**" ✅ |
| **命令** | ⭐ `'U'`（空闲字母只剩 `U`/`Z`）· 回包 `'u'` · **复位默认关 ⇒ ⛔ 零回归** ✅ |
| **控制板键** | ⭐ idx **13**（映射表里正是"备用"）⇒ ⭐ 脱离 PC 也能切 ✅ |
| **代码改动** | ⭐ **1 个寄存器 ＋ 1 处表达式**（见下） |
| **资源** | ⭐ **1 FF ＋ ~2 LUT ⇒ ≈ 0 CLS** ✅ |

```verilog
//  ⭐ 唯一的功能改动（⭐ `top.v`）
seq_arb ... .score_valid_i (SCORE_UART_ENABLE & ~guide_only_r ? ps_note_valid : 1'b0)
```

### 🟡 L2 · 提前亮（⭐ "可能提前一拍"）

| 项 | 内容 |
|---|---|
| **难点** | 🔴 `guide_lamp` 处理的是**到达它那一刻**的事件，而 `play_seq` 是**到 tick 才吐** ⇒ ⭐ **要提前，必须提前看到下一个事件** |
| 🔴 **不能怎么做** | ⛔ **给 `evt_buf` 加第二个读口** —— ⚠️ **BSRAM 只有 1 个读口**，且它已经被 `play_seq` 占用 ✅ |
| ✅ **怎么做（⭐ 便宜）** | ⭐ **在 `play_seq` 里预读**：⭐ `evt_buf` 是 **FWFT**（队头常驻）⇒ ⭐ **每次 pop 之后，队头就自动变成下一个事件** ⇒ ⭐ 把它**latch 进 `next_evt_q`** ⇒ ⭐ 再比 `cur_tick + lead >= next.tick` ⇒ ⭐ 提前输出预览 ✅ |
| **资源** | ⭐ **~64 FF ＋ ~25 LUT**（⭐ 一个 64 位保持寄存器 ＋ 一个 tick 比较器） |
| **提前量** | ⭐ 用 `localparam LEAD_TICK`（⛔ **不做除法器/乘法器**，⭐ 直接给常数或寄存器）✅ |
| **接口** | ⭐ `play_seq` 加 `pre_valid_o`/`pre_data_o` ⇒ ⭐ `guide_lamp.note_valid_i = ps_note_valid \| ps_pre_valid` ✅ |
| ⚠️ **风险** | ⭐ 提前亮之后，**到点还要再亮一次吗**？⭐ 语义要定：⭐ **提前亮 = 一直亮到真到点**（⭐ 不闪两下）✅ |

### 🔵 L3 · 省资源纪律（⭐ 你点名要求的）

| # | 纪律 | 为什么 |
|---|---|---|
| **R1** | ⛔ **不加 BSRAM** | ⭐ 余量 49 块，⚠️ 但**CLS 才是真瓶颈**（85%）⇒ ⭐ 加 BSRAM 会连带吃 CLS ✅ |
| **R2** | ⛔ **不加 DSP** | ⭐ 余量 96，⚠️ 但 DSP 会拉低 Fmax ✅ |
| **R3** | ⭐ **复用现成链** | ⭐ `guide_lamp`/`led_data`/`tlc5916_bank` **都已接好** ⇒ ⛔ 不重写 ✅ |
| **R4** | ⭐ **不新增计数器/分频** | ⭐ `blink_i` 已有（来自 `beat_gen`）⇒ ⭐ 直接复用 ✅ |
| **R5** | ⛔ **不做整段滚动 LED（L4）** | ⭐ 资源需求大；⭐ L1+L3 **已满足赛题** ✅ |
| **R6** | ⭐ **提前量用常数/寄存器** | ⛔ 不做"可调 ÷ 运算" ⇒ ⭐ 省 LUT/DSP ✅ |
| **R7** | ⭐ **每加一块立刻跑 PnR 量 CLS** | 🔴 ⛔ 不许攒着一起上（⭐ 本项目 CLS 余量只 4,660 ✅） |

---

## 四、⭐ 资源预算（⭐ 写码前先算清）

| 项 | FF | LUT | CLS | BSRAM | DSP |
|---|---|---|---|---|---|
| **当前余量** | 41,000 | 19,900 | **4,660** | 49 | 96 |
| **L1 指引模式** | +1 | +2 | **≈ 0** | 0 | 0 |
| **L2 提前亮** | +64 | +25 | **+10 ~ +30**（⚠️ CLS 非线性） | 0 | 0 |
| **合计** | **+65** | **+27** | **≤ +30** | **0** | **0** |

⇒ ⭐ **余量绰绰有余**（⭐ CLS 用掉不到 **0.7%**）✅
📌 ⚠️ **诚实标注**：⭐ 本项目 **CLS 是布局噪声主导的**（⭐ 实测同源重跑差 **±150**）
⇒ ⭐ 上面 "+10~30" **会淹没在噪声里** ⇒ ⭐ **验收时看"没有变差"，⛔ 不看精确增量** ✅

---

## 五、⭐ 验收判据（⭐ 每条都能失败，⛔ 不软）

### L1 指引模式

| # | 判据 | 怎么测 |
|---|---|---|
| **L1-a** | ⭐ 指引模式下：⭐ **`seq_arb.score_valid_i` 恒 0**（⭐ 音符不出声） | 顶层 tb 探针 |
| **L1-b** | ⭐ 指引模式下：⭐ **`guide_lamp` 位图照常更新**（⭐ `gl_guide_vis` 有变化） | ⭐ **这条必须有** —— ⚠️ 否则"静音"和"整条链坏了"分不清 ✅ |
| **L1-c** | ⭐ 指引模式下：⭐ **节拍器/鼓机照常**（⭐ `bg_beat`/`drum_gen` 不受影响） | 探针 |
| **L1-d** | ⭐ **普通模式（复位默认）行为逐位不变** | ⭐ 现有 tb **全绿**（零回归 ✅） |
| **L1-e** | ⭐ `'U'` 开关可逆（⭐ 开→关→开） | 串口 tb |

### L2 提前亮

| # | 判据 | 怎么测 |
|---|---|---|
| **L2-a** | ⭐ 预览**比真事件早 `LEAD_TICK` 个 tick** | ⭐ 模块 tb：喂两个事件，量提前量 ✅ |
| **L2-b** | ⭐ **提前量为 0 时行为与现状逐位相同**（⭐ 可退化成 L1） | ⭐ 同一 tb 换参数 ✅ |
| **L2-c** | ⭐ 预览**不吞事件**（⭐ 真事件到点仍照常输出） | ⭐ 这条防"提前亮把事件吃了" ✅ |
| **L2-d** | ⭐ 提前亮**不闪两下**（⭐ 一直亮到真到点） | 波形 |

### 通用

| # | 判据 |
|---|---|
| **G1** | ⭐ PnR：**0 setup / 0 hold** ＋ **6 道机械门全过** |
| **G2** | ⭐ 全量回归 **"通过数 == 共数"** |
| **G3** | ⭐ **上板可演示**（⭐ 视频要拍得出、决赛要复现得了 ✅） |

---

## 六、⭐ 执行序

| 序 | 任务 | 前置 | 交付 |
|---|---|---|---|
| **1** | ⭐ **L1 指引模式**（`'U'` ＋ 闸 `seq_arb.score` ＋ 键盘 idx 13） | ⭐ `'U'` 命令**已在 `calib_cmd` 加好**（9 处 ✅）⇒ ⏳ **只差 `top.v` 的闸门** | RTL ＋ 5 条判据 ＋ PnR |
| **2** | ⭐ **L1 上板确认**（⭐ 你烧进去听：⭐ 亮灯有、声音无、节拍器有） | 1 | 上板结论 |
| **3** | ⭐ **L2 提前亮**（`play_seq` 预读 ＋ `guide_lamp` 预览口） | ⭐ 2 通过（⚠️ L1 没确认前⛔ 不动 L2） | RTL ＋ 4 条判据 ＋ PnR |
| **4** | ⭐ **L2 上板调提前量**（⭐ 一拍 / 半拍 / 0） | 3 | 定值 |
| **5** | ⚠️ **可选**：L4 整段滚动 LED | ⭐ 资源允许才做 | — |

🔴 **⛔ 不做**：⭐ 手机 App 端 LED 自定义（⭐ 原文是"**可**搭载"，⭐ 属表面功夫 ✅）

---

## 七、⭐ 一句话

> ⭐ **L1 是 1 个寄存器 ＋ 1 处表达式**（⭐ 静音点正好在 `seq_arb.score_valid_i`，
> 而 LED 读的是它上游 ⇒ ⭐ 闸一下就行 ✅）；
> ⭐ **L2 是 1 个 64 位保持寄存器 ＋ 1 个比较器**（⭐ 靠 `evt_buf` 的 **FWFT** 特性，
> ⛔ **不需要第二个 BSRAM 读口** ✅）；
> ⭐ **两块合计 ≈ 65 FF ＋ 27 LUT ＋ ≤30 CLS ⇒ 用掉余量的 0.7%** ✅
