hokuu1102/Gowin2026-PolySynth/files/20-代码/待上机验证清单-20261014.md

# 待上机验证清单（2026-10-14）

**用途**：硬件一接上，照本清单**从上到下跑一遍**即可。
**预计总时长**：约 6~8 分钟（不含等待你插线）。
**最省事的做法**：直接跑最后的**第 5 步**（一条命令 15 项全跑）。

| 步骤 | 内容 | 需要什么 | 预期 |
|---|---|---|---|
| 0 | 确认板子在广播 | 只插 USB | 串口日志有 `advertising as "FPGA2026-Synth2"` |
| 1 | BLE 服务发现 | 只插 USB | `0xABF*` = 4 个 |
| 2 | 用真实 MIDI 灌谱 + 听 | USB + 网线（FPGA） | 和弦/鼓/BPM 三件事都听得出 |
| 3 | 串口屏（若有） | 屏接 `GPIO4/5` | 屏上播完/进度正常 |
| 4 | CH340 接回 | CH340 RX→GPIO17，共地 | `_uart1_wire_check` 200 帧逐字节一致 |
| 5 | ⭐ **一条命令全量** | 上面全部 | 离线 5/5 ＋ 真机全绿 |

---

## 0-A. 先看眼下的硬件状态（2026-10-14 夜间实测）

| 设备 | VID | 实测 |
|---|---|---|
| **ESP32 板子** | `303A` | **不在**（没插着）⇒ 第 0~3 步要等它插上 |
| **CH340** | `1A86` | **在，= COM31** ⇒ 第 4 步的上行链路可单独验 |

⭐ **所以第 4 步现在就能做**（⛔ 不用等板子）。但注意：
⚠️ `_uart1_wire_check.py` 要**同时**开上行口和日志口。若日志口（ESP32）不在，
它会打印 `⚠️ 没找到 ESP32 日志口（VID 303A）` 然后退回 `--port` 自己
⇒ 那个口已被自己占着 ⇒ **报"拒绝访问"**。
⇒ ⭐ **这是正常的**，⛔ 不是 bug —— 等板子插上后自然消失。

查端口（⛔ 不要手输 COM 号，端口会漂）：
```powershell
cd C:\Users\hokuu\Desktop\FPGA\FPGA2026-esp32\esp32\tools; python -c "import sys;sys.path.insert(0,'.');from run_all_tests import find_port,VID_ESP32,VID_CH340;print('ESP32 =',find_port(VID_ESP32));print('CH340 =',find_port(VID_CH340))"
```

---

## 0. 确认板子在广播（只要插着 USB）

⭐ 一条单行命令（不含换行，可直接粘贴）：

```powershell
cd C:\Users\hokuu\Desktop\FPGA\FPGA2026-esp32\esp32\tools; python -X utf8 read_log.py --port COM29 --baud 115200 --seconds 4 | Select-String 'advertising|set_rand_addr'
```

⚠️ 端口会漂 ⇒ 先用上面 0-A 的办法查 ESP32 实际的口，把 `COM29` 换成它。
⚠️ `read_log.py` 只有 `--port/--baud/--seconds/--reset/--save`
⇒ ⭐ **没有 `--grep`**，过滤用 PowerShell 的 `Select-String`（上面就是这样）。

**预期**：
```
set_rand_addr XX:XX:XX:XX:20:26 -> ESP_OK
advertising as "FPGA2026-Synth2"
```
⚠️ 地址每次上电**都不同**（这是设计如此 —— 绕开 Windows 的 MAC 级 GATT 缓存）。
⛔ 若没有这两行 ⇒ 板子没起来，先按 `build.ps1 -Action flash -Port COM29` 重烧。

---

## 1. BLE 服务发现（本轮最要命的那个）

```powershell
python stat_read.py --scan-timeout 25
```

**预期**：打印 8 组（`V1/pool/ring/ble/uart/hmi/frame/cmd`）＋ `✅ 结构完整`
**判据**：退出码 `0`。⛔ 退出码非 0 或报"没找到 FPGA2026-Synth" ⇒ BLE 那条还没通。

📌 顺带看这几行（本轮修的都能在这验）：
```
pool=... lead=1200 ...        ← lead 不再是 20000（10.4 秒 → 0.62 秒）
        ^^^^ 应是 1200 或更小
```

---

## 2. ⭐ 用真实 MIDI 灌谱（本轮三个用户报告的修复）

### 2.1 先离线确认转换对不对（⛔ 不用上板）

```powershell
node _diag_bpm.js 'C:\Users\hokuu\Downloads\09_Conjurer.mid'
```

**预期**（本轮刚修的）：
```
文件里的 tempo 事件 = 7 个
    #0  BPM 168.000    #1  BPM 160.000   #2  BPM 165.000
    #3  BPM 167.000    #4  BPM 160.000   #5  BPM 165.000   #6  BPM 168.000
我方实际发出的 kind=2 事件 = 7 个      ← 🔴 必须也是 7 个（原来只发 1 个）
```

```powershell
node _diag_chord.js 'C:\Users\hokuu\Downloads\6.世界悲(已修订).mid'
```

**预期**：逐轨"和弦数（原始 → 转换后）"**全部一致**（Guitar I 526 · II 67 · Drum 568）。

```powershell
node _diag_concurrency.js 'C:\Users\hokuu\Downloads\6.世界悲(已修订).mid'
```

**预期**：`旋律部分峰值并发 = 10` · `是否用到 axis 14 = 否` · `✅ 够用（余量 5 条）`

### 2.2 上板听

1. 浏览器开 **`http://127.0.0.1:8777/score_studio.html`**
   ⚠️ 必须 `Ctrl+F5` 强制刷新 —— 右上角看"构建 MM-DD HH:MM"是不是今天
2. 点**连接蓝牙** → 选 `FPGA2026-Synth*`（名字每次上电可能带不同尾号）
3. 拖入 MIDI → 看日志：
   ```
   MIDI 解析成功：xxxx 个事件 · BPM 168.0 · 480 PPQN → 960
   ⚠️ 该谱子有 7 个 tempo 点（变速）—— 已全部转成 kind=2 事件
   轨分配（鼓优先，其余按音色归组）：
     Guitar I → axis 0,1,2,3 · GUITAR · xxxx 个音符     ← ⭐ 现在是"多条轴"
   ```
   ⭐ 左下角图例应是 **4~5 种颜色**（BASS/GUITAR/PIANO/PAD + 鼓），⛔ 不是 10 种
4. 点**一键上传** → 应看到**进度条走动** + 日志 `上传完成：xxx 字节 / xxx 个事件，用时 x s，xx KB/s`
   ⛔ 若卡在"清池"后不动 ⇒ **立刻报**（这是上轮修的死锁，可能还有别的路径）
5. 点**起播** → 听：
   - **和弦**：下拨那一下应该是**多个音同时响**（⛔ 原来只响一个）
   - **鼓**：底部有**独立一栏**（Kick/Snare/HiHat/Tom 四行），⛔ 不再混在钢琴卷帘里
   - **速度**：应是 **168 BPM**（⛔ 原来是 120）
6. 试**选轨**：取消勾几条轨再灌 ⇒ 只听剩下的

---

## 3. 串口屏（若接着）

硬件：屏 `TX → ESP32 GPIO5` · `RX ← ESP32 GPIO4` · **共地**

```powershell
# ⚠️ 下面两条是【独立】命令，逐行跑（第一行里的 COM29 换成实际日志口）
python hmi_states_check.py --events 200 --log-port COM29
python hmi_song_check.py
```

**预期**：两条都 `结论：全部通过`（含 `LINK_LOST`/`L4_RECOVER` 判据）。

📌 **重点看这轮修的起播提前量**：
- 点起播后，屏上应在 **~0.6 秒**内开始动（⛔ 原来要 10.4 秒）
- 放完后 `sent` 会等于池内帧数

---

## 4. CH340 接回（接上真 FPGA 的前提）

硬件：`CH340 RXD ← ESP32 GPIO17` · `CH340 TXD → ESP32 GPIO18` · **共地**

```powershell
# ⚠️ 端口会漂，先查出 CH340 的口再传进去（这一行直接跑，⛔ 别手填COM号）
$ch = (python -X utf8 -c "import sys;sys.path.insert(0,'.');from run_all_tests import find_port,VID_CH340;print(find_port(VID_CH340))"); if ($ch -eq 'None') { Write-Host 'RED CH340 不在'; return }; python -X utf8 _uart1_wire_check.py --port $ch --events 200 --seconds 25
```

**预期**：`线上 200 帧 events【逐字节一致】`
⛔ 报"前 0 帧" ⇒ 线没接 / 没共地（⛔ 不是代码问题）

---

## 5. ⭐ 一条命令全量（最省事）

```powershell
python run_all_tests.py
```

**预期（本轮目标）**：`合计 15 项：通过 15 · 失败 0`
**当前实际**：`通过 13 · 失败 2`（那 2 项 = CH340 未接，接上第 4 步后应变 0）

### 若全绿后还要做

```powershell
# 连跑 3 轮确认稳定（⛔ 不是一次侥幸）
1..3 | ForEach-Object { python run_all_tests.py; Start-Sleep 3 }
```

---

## ⛔ 若某项红了的排查入口

| 症状 | 先看这个 |
|---|---|
| `没找到 FPGA2026-Synth` | 板子没在广播 ⇒ 回第 0 步 |
| `0xABF3 not found` / 只 4 个特征 | BLE 那条⇒ 回第 1 步；⛔ **不要改 RTL** |
| `前 0 帧` | CH340 接线 ⇒ 第 4 步 |
| 上传卡住没进度条 | 🔴 **立刻报**（死锁可能没修干净） |
| `xxx is not defined` | 同上（这轮踩过 2 次未定义引用） |
| 和弦仍只响一个音 | FPGA 侧 `same_hit` ⇒ 看追问文档是否已答复 |

## 📌 已知未解决（⛔ 不是你的操作问题）

- **鼓同时敲会互抢**（568 次）⇒ 等 FPGA 侧答复
  `files/20-代码/ESP32侧追问-同时敲多个鼓与same_hit-20261014.md`
- **XOR 校验口径**：他们说"以我方为准、他们改"，但 RTL 未落实 ⇒ 联调若报"坏校验"就是这个
- **14 B 上行帧**：等他们出含改动的位流

`powershell
cd /tmp
python foo.py --bar
`
