hokuu1102/Gowin2026-PolySynth/files/20-代码/心跳灯快闪排查清单-20261013.md

# 🔴 心跳灯快闪 + 没声音 —— 排查清单（2026-10-13）

> ⭐ **症状**：⭐ 接了**扩展板**之后 ⭐ **心跳灯一直快闪** ＋ ⭐ **没声音** ✅
> ⚠️ **前提**：⭐ 你烧的是**之前的码流** ✅ ⇒ ⭐ 本周期新加的 4 个故障源**不在里面** ✅
> ⇒ ⭐ 所以快闪只可能来自 ⭐ **老的三个源** ✅

---

## 〇、⭐ 先搞清"快闪"是什么

⭐ 心跳灯的分频由 ⭐ **`fault_sticky`** 控制 ✅：

```verilog
wire [31:0] hb_div_eff = fault_sticky ? (HEARTBEAT_DIV >> 3) : HEARTBEAT_DIV;
```

⭐ `HEARTBEAT_DIV >> 3` = ⭐ **快 8 倍** ✅ ⇒ ⭐ 这就是"快闪" ✅
⭐ 而 ⭐ `fault_sticky` = ⭐ **`fault_any_w` 的 sticky**（⭐ 只复位才清 ✅）

### ⭐ 老码流里 `fault_any_w` 的**全部**来源（⭐ 只有 3 个 ✅）

| ⭐ # | ⭐ 源 | ⭐ 含义 |
|---|---|---|
| ⭐ **1** | ⭐ ⭐ **`\|af_fault`** | ⭐ **`adc_farm` 的 SPI / 片选故障** ✅ ← ⭐ **接扩展板后最可疑** 🔴 |
| ⭐ **2** | ⭐ ⭐ **`mx_fault`** | ⭐ **`tdm_render_mixer` 的渲染超时**（⭐ `deadline_fault_o` ✅）← ⭐ **会导致没声音** 🔴 |
| ⭐ **3** | ⭐ `ovf_any` | ⭐ 事件丢失/溢出 ✅ |

✅ ⭐ **`fault_sticky` 【不会】静音** ✅ —— ⭐ 它**只驱动心跳灯** ✅（⭐ 我核对过 ✅）
⇒ ⭐ ⭐ **所以"快闪"和"没声音"是【两个】症状** ✅，⭐ 可能同源、⭐ 也可能不同源 ✅

---

## 一、⭐ 5 分钟初判（⭐ 不用仪器 ✅）

> 🔴🔴 ⭐⭐ **2026-10-13 更正**：⭐ 我第一版把"**拔掉扩展板**"当第一步 ✅ —— ⚠️ **那是错的** ✅
> ⭐ 用户实测：⭐ **不接线时心跳也会闪** ✅ ⇒ ⭐ 拔掉**不会有任何变化** ✅（⭐ 扩展板只是**接线板** ✅）
> ⇒ ⭐ ⭐ **快闪是【常态】** ✅ ⇒ ⭐ 应该按 ⭐ **"恒为高"** 去查 ✅，⭐ ⛔ 不是按"接错线"查 ✅

| ⭐ 步 | ⭐ 操作 | ⭐ 看什么 |
|---|---|---|
| ⭐ ⭐ **1** | ⭐ ⭐ **上电复位后【立刻】看灯** ✅ | ⭐ **一上电就快闪** ⇒ ⭐ ⭐ **sticky 把【开机瞬间】的一次超时锁住了** ✅（⭐ 见 §一之二 ✅）<br>⭐ **先慢闪、⭐ 过一会儿才快闪** ⇒ ⭐ 是**运行中**真的超时 ✅ |
| ⭐ **2** | ⭐ **量时钟**：⭐ 音频主时钟 / ⭐ `serial_clk` / ⭐ `pixel_clk` | ⭐ ⭐ **先确认 `PLL` 锁了** ✅ —— ⭐ 时钟不对 ⇒ ⭐ **既超时又没声音** ✅（⭐ 一个根因两个症状 ✅） |
| ⭐ **3** | ⭐ **量 3.3V / 1.2V / 2.5V** | ⭐ 电压**偏低** ⇒ ⭐ 时序余量被吃 ⇒ ⭐ 踩到那 **3 拍**的余量 ✅ |
| ⭐ **4** | ⭐ 摸一下芯片 | ⭐ **发烫** ⇒ ⭐ 短路/过流 ✅ |
| ⭐ **5** | ⭐ **放音** | ⭐ **有声吗** ✅ ⇒ ⭐ 见 §三 ✅ |

---

## 一之二、⭐ ⭐ **最可能的真凶：`mx_fault`**（⭐ 已从代码确认 ✅）

### ⭐ 为什么**只可能**是它

⭐ `rtl/drivers/adc_farm.sv:222` 的注释**原文** ✅：
> ⭐ *"⭐ `assign fault_any_w = (|af_fault) | mx_fault;` ⇒ ⭐ **`|af_fault` 恒 0** ✅
> ⇒ 🔴 **心跳灯的'快闪'只能由 `mx_fault` 触发**"* ✅

⇒ ⭐ ⭐ **你那个旧码流里 `af_fault` 永远是 0** ✅（⭐ 那是 `P1-28`／2026-10-09 **之后**才修好的 ✅）
⇒ ⭐ ⭐ **所以快闪【只可能】来自 `mx_fault`** ✅ ✅

### ⭐ 它是什么

| ⭐ 项 | ⭐ 值 |
|---|---|
| ⭐ 信号 | ⭐ `tdm_render_mixer.deadline_fault_o` ✅ |
| ⭐ 含义 | ⭐ **一帧渲染没在 `RENDER_DEADLINE_CYC` 内完成** ✅ |
| ⭐ ⭐ **性质** | ⭐ ⭐ **sticky** ✅ —— ⭐ `:36` 原文：⭐ *"⭐ 一旦超时**永久置位** ✅，⛔ 不会被后续正常帧掩盖 ✅"* ✅ |
| ⭐ 后果 | ⭐ ⭐ **历史上【曾经】错过一次 ⇒ ⭐ 灯就永久快闪** ✅ ✅ |

⇒ ⭐ ⭐ **这正好解释"⭐ 不接线也闪 ✅"** ✅ —— ⭐ 它跟接线**根本无关** ✅

### 🔴 ⭐ 而且**余量本来就只有 3 拍**（⭐ 这是关键 ✅）

⭐ `:107` 原文 ✅：
> ⭐ *"⭐ `cnt >= 31` 就置 `deadline_fault`，⭐ 而 `cnt` **每帧都要走到 34**"* ✅

⇒ ⭐ ⭐ **余量 = 34 − 31 = 3 拍** 🔴 ⇒ ⭐ **时钟频率/时序稍有偏差就会踩线** ✅ ✅
⇒ ⭐ ⭐ **所以第一件要量的是【时钟】** ✅（⭐ ⛔ 不是接线 ✅）

### ⭐ 怎么区分"开机瞬态"和"运行中真超时"

| ⭐ 现象 | ⭐ 结论 | ⭐ 方向 |
|---|---|---|
| ⭐ **上电立刻快闪** ✅ | ⭐ 开机瞬间**错过一次**，⭐ 被 sticky **锁住** ✅ | ⭐ 查**复位释放时序** / ⭐ PLL 锁定前那段 ✅ |
| ⭐ 先慢闪、⭐ 一会儿才快闪 ✅ | ⭐ **运行中**真的超时 ✅ | ⭐ 查**时钟频率** / ⭐ 温度 / ⭐ 供电 ✅ |
| ⭐ **复位按钮按一下**，⭐ 立刻又闪 ✅ | ⭐ 每次开机都超时 ⇒ ⭐ **必然事件** ✅ | ⭐ 时钟/配置 ✅ |

📌 ⭐ **复位一下就清 sticky** ✅ ⇒ ⭐ ⭐ **"按复位后多久开始闪"是最好的判据** ✅

---

## 二、⭐ SPI / ADC 接线（⭐ 最可疑 ✅）

⭐ 这套 ADC 是 ⭐ **2 片 `MCP3208`** ✅（⭐ 左右手板 ✅）⭐ 走 ⭐ **同一组 SCLK/MOSI ＋ ⭐ 各自独立的 MISO/CS** ✅

| ⭐ 信号 | ⭐ FPGA 脚 | ⭐ J9 排针 | ⭐ 方向 |
|---|---|---|---|
| ⭐ `spi_sclk` | ⭐ **E14** | ⭐ **N1** | ⭐ 出 |
| ⭐ `spi_mosi` | ⭐ **E13** | ⭐ **N2** | ⭐ 出 |
| ⭐ `spi_miso[0]` | ⭐ **C15** | ⭐ **N3** | ⭐ 入 |
| ⭐ `spi_cs_n[0]` | ⭐ **C14** | ⭐ **N4** | ⭐ 出 |
| ⭐ `spi_miso[1]` | ⭐ **B13** | ⭐ **N5** | ⭐ 入 |
| ⭐ `spi_cs_n[1]` | ⭐ **C13** | ⭐ **N6** | ⭐ 出 |
| ⭐ `spi_miso[2..5]` / ⭐ `spi_cs_n[2..5]` | ⭐ A14/A13 · ⭐ B16/B15 · ⭐ A16/A15 · ⭐ A20/B20 | ⭐ N7..N16 | ⭐ **预留**（⭐ 本设计**不用** ✅） |

### 🔴 ⭐ 三条**硬约束**（⭐ 违反必然 `af_fault` ✅）

| ⭐ # | ⭐ 约束 | ⭐ 为什么 |
|---|---|---|
| ⭐ **1** | ⭐ ⭐ **每片的 `MISO` 必须【独立】** ✅（⭐ `K-06` ✅） | ⭐ 两片是 ⭐ **锁步并行**（⭐ 同时选中 ✅）⇒ 🔴 若 `MISO` 并在一起 ⇒ ⭐ **两个输出对打** ⇒ ⭐ 数据必错 ＋ ⭐ 可能**打坏 IO** 🔴 |
| ⭐ **2** | ⭐ ⭐ **`CS` 不能接反** ✅ | ⭐ `CS` 错片 ⇒ ⭐ 读到的数据属于**另一片** ⇒ ⭐ 音高全错 ✅ |
| ⭐ **3** | ⭐ ⭐ **共地** ✅ | ⭐ 不共地 ⇒ ⭐ SPI 电平飘 ⇒ ⭐ 偶发/必错 ✅ |

### ⭐ 具体怎么查

| ⭐ 步 | ⭐ 操作 |
|---|---|
| ⭐ 1 | ⭐ **万用表蜂鸣档**：⭐ 量 `MISO[0]`（⭐ N3 ✅）与 ⭐ `MISO[1]`（⭐ N5 ✅）⭐ **之间是否短路** 🔴 ⇒ ⭐ **必须不通** ✅ |
| ⭐ 2 | ⭐ 量 ⭐ `MISO` 对 **GND** 是否短路 ✅ · ⭐ 对 **3.3V** 是否短路 ✅ |
| ⭐ 3 | ⭐ 量 ⭐ `CS[0]`（⭐ N4 ✅）/ ⭐ `CS[1]`（⭐ N6 ✅）⭐ 到**对应那片**的 `CS` 脚 ✅ ⇒ ⭐ 是否**接对片** ✅ |
| ⭐ 4 | ⭐ 量 ⭐ `SCLK`（⭐ N1 ✅）/ ⭐ `MOSI`（⭐ N2 ✅）⭐ 到**两片**都通 ✅ |
| ⭐ 5 | ⭐ 示波器/逻辑分析仪看 ⭐ **`SCLK` 有没有波形** ✅ ⇒ ⭐ 没有 ⇒ ⭐ 主控侧就没在发 ✅ |
| ⭐ 6 | ⭐ 看 ⭐ **`MISO` 上有没有【两片同时驱动】**（⭐ 电平在 1.65V 附近 ✅）⇒ ⭐ 有 ⇒ ⭐ **并线了** 🔴 |

📌 ⭐ **`MISO` 上拉**：⭐ 建议各加 **10 kΩ 上拉** ✅（⭐ 2026-10-01 更正为"非必需" ✅，⭐ 但**接扩展板后**值得加 ✅）

---

## 三、⭐ 没声音（⭐ 与 `mx_fault` 相关 ✅）

⭐ `mx_fault` = ⭐ **`tdm_render_mixer` 的渲染超时** ✅ ⇒ 🔴 **它会让声音断掉** ✅

| ⭐ 步 | ⭐ 操作 | ⭐ 判据 |
|---|---|---|
| ⭐ 1 | ⭐ **先看时钟**：⭐ 量 ⭐ 音频主时钟 / ⭐ `serial_clk` / ⭐ `pixel_clk` | ⭐ 有波形吗？⚠️ 没有 ⇒ ⭐ `PLL` 没锁 ✅ |
| ⭐ 2 | ⭐ 量 ⭐ **DAC/I2S 的输出脚** | ⭐ 有没有在动？（⭐ 有数据在跑 ✅） |
| ⭐ 3 | ⭐ **拔掉扩展板**再放音 | ⭐ 有声 ⇒ ⭐ 扩展板**抢了**音频脚 或 ⭐ 拉了供电 ✅ |
| ⭐ 4 | ⭐ 查 ⭐ **`constr/top.cst` 里音频脚的分配** | ⭐ 扩展板是否**复用了**同样的排针 ⚠️（⭐ 冲突 ✅） |

⚠️ ⭐ **最可能的一条**：⭐ 扩展板**占用了**音频输出脚 ⭐ 或 ⭐ 把 ⭐ **3.3V 拉低** ✅ ⇒ ⭐ 两者都会"没声音" ✅

---

## 四、⭐ 如果还想进一步定位（⭐ 推荐 ✅）

⭐ ⭐ **烧【本周期的新码流】** ✅ —— ⭐ 它的诊断能力**强得多** ✅：

| ⭐ 新码流多出来的 | ⭐ 作用 |
|---|---|
| ⭐ ⭐ **`as_seen`（⭐ 16 轴"见过"位图 ✅）** | ⭐ **直接告诉你哪个轴没采到** ✅ ⇒ ⭐ 一眼看出是**哪片/哪根线** ✅ |
| ⭐ ⭐ **帧流失步**（⭐ `eu_frame_cnt`/⭐ `eu_resync_cnt` ✅） | ⭐ 区分"⭐ 是 ADC 坏了"还是"⭐ 是曲谱口坏了" ✅ |
| ⭐ ⭐ **`at_skip`/⭐ `at_fail`**（⭐ autotare ✅） | ⭐ 哪个轴**零点没记上** ✅ |
| ⭐ ⭐ **`cfg_warn`**（⭐ 参数告警 ✅） | ⭐ 参数配错 ✅ |

📌 ⭐ **判据**：⭐ 新码流上 ⭐ 若 ⭐ **`as_seen != 全 1`** ✅ ⇒ ⭐ **有轴没被采到** ✅ ⇒ ⭐ 直接指向**那一片的接线** ✅
⚠️ ⭐ 而新码流**正常时灯是【慢闪】** ✅ ⇒ ⭐ 快闪就是**真故障** ✅

---

## 五、⭐ 一张速查表

| ⭐ 现象 | ⭐ 最可能 | ⭐ 第一步 |
|---|---|---|
| ⭐ 快闪 ＋ ⭐ 没声音 ＋ ⭐ **拔掉扩展板就好了** | ⭐ 扩展板接线/供电 🔴 | ⭐ §二 的 6 步（⭐ 重点：⭐ `MISO` 是否并线 ✅） |
| ⭐ 快闪 ＋ ⭐ **有声音** | ⭐ `af_fault`（⭐ ADC ✅） | ⭐ §二 |
| ⭐ 快闪 ＋ ⭐ **没声音** ＋ ⭐ 拔掉扩展板**还是没声** | ⭐ `mx_fault`（⭐ 渲染超时 ✅） | ⭐ §三 |
| ⭐ **慢闪** ＋ ⭐ 没声音 | ⭐ **不是** `fault_any_w` ✅ ⇒ ⭐ 查别处（⭐ 按键/⭐ 音频脚 ✅） | ⭐ §三-1/2 |

📌 ⭐ **判据**：⭐ **"拔掉扩展板"这一步最关键** ✅ —— ⭐ 一次就能把范围**砍一半** ✅

---

# 六、⭐⭐ 追加（⭐ 2026-10-13 晚）：⭐ **"之前杜邦线正常，现在不正常" ⇒ 逐条对照** ✅

> ⭐ **用户关键信息**：⭐ **之前用杜邦线是正常的** ✅ ⇒ ⭐ 所以 ⭐ **问题在"哪些线变了"** ✅
> 🔴 ⭐ 并且 ⭐ 我上一条的"拔掉扩展板"**是错的** ✅（⭐ 用户实测：⭐ 不接线也会闪 ✅）

## ⭐ 6.0 ⭐ 先更正一处：⭐ "余量只有 3 拍"**是错的** ✅

⭐ 我引用了 `tdm_render_mixer.v:107` 的 ⭐ *"⭐ `cnt >= 31` 就置 `deadline_fault` ✅"* —— ⚠️ **那是在描述一个【已修复的 bug】** ✅：

📄 `:105-113` 原文 ✅：
> ⭐ *"⚠️⚠️ 2026-09-21 实测踩坑（⭐ `K-99` ✅）：⭐ ⛔ **不能写 `RENDER_DEADLINE_CYC[LW:0]`**
> —— ⭐ 那是**对参数做位选**，⭐ 会把 927 截成 `927 mod 64 = 31` ✅
> ⇒ 🔴 **正常配置下每帧都误报超时** ✅
> ⇒ ⭐ 正确做法：⭐ **饱和到 `cnt` 能表示的最大值**（⭐ ⛔ 不是截断 ✅）"* ✅

⇒ ⭐ ⭐ **所以截止是 ~927 拍（⭐ 很宽松 ✅）** ✅
⇒ ⭐ ⭐ **`mx_fault` 触发 = 【真的卡住了】** ✅ —— ⭐ ⛔ 不是"差一点没赶上" ✅ ✅

## ⭐ 6.1 ⭐ 板载 vs 板上（⭐ 先分清哪些"拔不掉" ✅）

| ⭐ 外设 | ⭐ 引脚 | ⭐ 在哪 | ⭐ 拔掉会怎样 |
|---|---|---|---|
| ⭐ ⭐ **时钟** | ⭐ `clk` = **V22**（⭐ 专用 GCLK ✅） | ⭐ ⭐ **板载晶振** ✅ | ⭐ ⛔ **拔不掉** ✅ ⇒ ⭐ **⛔ 不是它** ✅ |
| ⭐ ⭐ **音频 DAC ＋ 功放** | ⭐ `I2S2_BCK`=**F20** · ⭐ `LRCK`=**E22** · ⭐ `DIN`=**D22** ✅ | ⭐ ⭐ **板载**（⭐ PT8211-S ＋ ⭐ NS4263 ✅） | ⭐ ⛔ **拔不掉** ✅ ⇒ ⭐ ⚠️ 但要**外接喇叭/耳机** ✅ |
| ⭐ ⭐ **ADC（⭐ 2 片 MCP3208 ✅）** | ⭐ `spi_*` = ⭐ **J9·N1~N6** ✅ | ⭐ ⭐ **拓展板上** 🔴 | ⭐ ⭐ **没数据 ⇒ ⭐ 没声音** ✅ |
| ⭐ ⭐ **按键灯（⭐ TLC5916 链 ✅）** | ⭐ `led_le`=**A21**(N17) · ⭐ `sdi`=**B21**(N18) · ⭐ `clk`=**B18**(N19) · ⭐ `oe_n[0..4]`=**B17/C17/D17/A19/A18**(N20~N24) ✅ | ⭐ ⭐ **拓展板上** 🔴 | ⭐ 灯不亮（⭐ 但**不影响声音** ✅） |
| ⭐ **灯带（⭐ WS2812 ✅）** | ⭐ `ws_strip_o[0]` = **W19**（⭐ PMOD1 针 11 ✅） | ⭐ ⭐ **拓展板上** ✅ | ⭐ 灯带不亮 ✅ |
| ⭐ **复位** | ⭐ `rst_n` = **AA13** ✅ | ⭐ 板载按钮 ✅ | ⭐ |
| ⭐ **心跳灯** | ⭐ `led_heartbeat` = **V13** ✅ | ⭐ 板载 ✅ | ⭐ 就是它在闪 ✅ |

## ⭐ 6.2 ⭐⭐ **逐条对照：⭐ 哪根线漏了/接错 ⇒ ⭐ 什么症状** ✅

### 🔴 ⭐ A. ⭐ 最可疑：⭐ ADC 的 SPI（⭐ 它直接决定"有没有声音" ✅）

| ⭐ 线 | ⭐ FPGA 脚 | ⭐ J9 | ⭐ ⭐ **漏接 / 接错 ⇒ 症状** ✅ |
|---|---|---|---|
| ⭐ ⭐ **`spi_miso[0]`** | ⭐ **C15** | ⭐ **N3** | ⭐ ⭐ **数据恒 0 或 恒 1** ⇒ ⭐ 所有轴读数**一样** ⇒ 🔴 **要么全"没按"（没声音）**⭐ 要么**全"按住"（16 声部齐响 ⇒ 卡死 ⇒ `mx_fault` 快闪）** ✅ |
| ⭐ ⭐ **`spi_miso[1]`** | ⭐ **B13** | ⭐ **N5** | ⭐ 同上（⭐ 右板 ✅） |
| 🔴 ⭐ ⭐ **`MISO[0]` 与 ⭐ `MISO[1]` 并在一起** | ⭐ — | ⭐ — | 🔴 ⭐ ⭐ **两片同时驱动 ⇒ 电平在 1.65V 附近 ⇒ 数据必错** ✅ ⇒ ⭐ 全轴乱 ⇒ ⭐ **16 声部齐响 ⇒ 卡死 ⇒ `mx_fault`** ✅<br>⚠️ 而且 ⭐ **可能打坏 IO** 🔴 |
| ⭐ ⭐ **`spi_cs_n[0]`** | ⭐ **C14** | ⭐ **N4** | ⭐ 左片**永不响应** ⇒ ⭐ 左 8 轴恒 0 ✅ |
| ⭐ ⭐ **`spi_cs_n[1]`** | ⭐ **C13** | ⭐ **N6** | ⭐ 右片**永不响应** ⇒ ⭐ 右 8 轴恒 0 ✅ |
| ⭐ ⭐ **`spi_sclk`** | ⭐ **E14** | ⭐ **N1** | ⭐ ⭐ **完全没有数据** ⇒ 🔴 **全轴恒 0 ⇒ 没声音** ✅ |
| ⭐ ⭐ **`spi_mosi`** | ⭐ **E13** | ⭐ **N2** | ⭐ 通道选择命令发不出去 ⇒ ⭐ 读到的通道**全乱** ✅ |
| ⭐ ⭐ **ADC 的 3.3V / GND** | ⭐ — | ⭐ — | ⭐ 片不工作 ⇒ ⭐ 数据恒 0/恒 1 ✅ |
| ⭐ ⭐ **共地**（⭐ FPGA 与 ⭐ ADC 板 ✅） | ⭐ — | ⭐ — | 🔴 ⭐ 电平**飘** ⇒ ⭐ 数据**乱跳** ⇒ ⭐ 全轴乱按 ⇒ ⭐ **卡死 ⇒ `mx_fault`** ✅ |

### ⭐ B. ⭐ 按键灯（⭐ `TLC5916` ✅）—— ⚠️ 只影响灯

| ⭐ 线 | ⭐ 漏接 ⇒ 症状 |
|---|---|
| ⭐ `led_le`（⭐ A21 ✅） | ⭐ 锁存不动作 ⇒ ⭐ 灯**不亮/不更新** ✅ |
| ⭐ `led_sdi`（⭐ B21 ✅） | ⭐ 灯**不亮** ✅ |
| ⭐ `led_clk`（⭐ B18 ✅） | ⭐ 灯**不亮** ✅ |
| ⭐ `led_oe_n[0..4]`（⭐ B17/C17/D17/A19/A18 ✅） | ⭐ 对应的**那几路灯常亮或常灭** ✅ |

📌 ⭐ **这一组⛔ 不会造成"没声音"** ✅ ⇒ ⭐ 如果**声音正常只是灯不亮** ✅ ⇒ ⭐ 就查这里 ✅

### ⭐ C. ⭐ 音频（⭐ 板载 ✅）—— ⚠️ 只差"外接喇叭"

| ⭐ 项 | ⭐ 漏接 ⇒ 症状 |
|---|---|
| ⭐ ⭐ **喇叭/耳机** ✅ | ⭐ ⭐ **没声音**（⭐ 但 ⭐ **灯是慢闪** ✅ —— ⭐ 这是**最容易误判**的一条 ✅） |
| ⭐ `I2S2_*`（⭐ 板载连线 ✅） | ⭐ 板载的，⭐ 一般不会断 ⚠️（⭐ 除非焊点虚 ✅） |

### ⭐ D. ⭐ 其它

| ⭐ 线 | ⭐ 漏接 ⇒ 症状 |
|---|---|
| ⭐ `rst_n`（⭐ AA13 ✅） | ⭐ 复位按钮**失灵** ✅（⭐ ⚠️ 但 ⭐ **上电复位仍然有效** ✅） |
| ⭐ `ws_strip_o`（⭐ W19 ✅） | ⭐ 灯带**不亮** ✅ |

## ⭐ 6.3 ⭐⭐ 我的**最佳猜测**（⭐ 按"同时解释快闪 ＋ 没声音"排序 ✅）

| ⭐ 排序 | ⭐ 原因 | ⭐ 为什么能同时解释两个症状 |
|---|---|---|
| ⭐ ⭐ **1** | ⭐ ⭐ **ADC 的 MISO / CS / 共地 有问题** ✅ | ⭐ 读数**乱** ⇒ ⭐ 16 个轴**全被当成"按住"** ⇒ 🔴 **16 声部齐响 ⇒ 渲染卡死 ⇒ `mx_fault` 快闪** ✅ ⭐ 而音符是**垃圾** ⇒ ⭐ 听起来**没声音**（⭐ 或只是噪声 ✅） |
| ⭐ **2** | ⭐ **MISO[0] 与 ⭐ MISO[1] 并线** ✅ | ⭐ 同上，⭐ 而且**更确定**（⭐ 两片对打 ✅） |
| ⭐ **3** | ⭐ **喇叭/耳机 没插** ✅ ＋ ⭐ 另一个原因导致快闪 | ⭐ 两个**独立**问题 ✅ |

## ⭐ 6.4 ⭐⭐ **最快的判别实验**（⭐ 5 分钟 ✅）

| ⭐ 实验 | ⭐ 结果 ⇒ 结论 |
|---|---|
| ⭐ ⭐ **把 ADC 的 `MISO` 两根都【断开】**（⭐ 不接 ✅） | ⭐ 若**灯变成慢闪** ✅ ⇒ ⭐ **确认是 ADC 读数乱** ✅（⭐ 因为断开后 ⭐ 读数恒 0 ⇒ ⭐ 没有声部 ⇒ ⭐ 不卡 ✅）<br>⭐ 若**还是快闪** ✅ ⇒ ⭐ 不是 ADC ⇒ ⭐ 查时钟/别的 ✅ |
| ⭐ ⭐ **量 `MISO[0]`（⭐ N3 ✅）与 ⭐ `MISO[1]`（⭐ N5 ✅）之间的电阻** ✅ | ⭐ **导通** 🔴 ⇒ ⭐ **并线了**（⭐ 必须改 ✅） |
| ⭐ ⭐ **按一下复位，⭐ 看多久开始闪** ✅ | ⭐ **立刻闪** ⇒ ⭐ 复位那一下就超时了 ⇒ ⭐ 查复位/PLL ✅<br>⭐ **过一会儿才闪** ⇒ ⭐ 运行中卡 ✅ |
| ⭐ ⭐ **只接电源，⭐ 不接任何信号线** ✅ | ⭐ 还闪 ⇒ ⭐ 与信号线无关 ⇒ ⭐ 是 FPGA 侧/时钟 ✅ |

📌 ⭐ ⭐ **判据**：⭐ **"把 MISO 两根断开后灯变慢闪"** ✅ 是最有力的一条 ✅ —— ⭐ 它同时证明了"⭐ ADC 读数乱"＋"⭐ 读数乱会导致 `mx_fault`" ✅

---

# 七、⭐ 串口引脚（⭐ 2026-10-13 补 ✅）

## ⭐ ① ⭐ **调试串口**（⭐ USB-TTL ✅）—— ⭐ 就是你要问的这两个 ✅

| ⭐ 信号 | ⭐ FPGA 脚 | ⭐ **J9 排针** | ⭐ 方向 | ⭐ 接什么 |
|---|---|---|---|---|
| ⭐ ⭐ **`uart_rx`** | ⭐ **D14** | ⭐ ⭐ **N26** | ⭐ **入** | ⭐ ⭐ **接 USB-TTL 的 `TX`** ✅ |
| ⭐ ⭐ **`uart_tx`** | ⭐ **D15** | ⭐ ⭐ **N25** | ⭐ **出** | ⭐ ⭐ **接 USB-TTL 的 `RX`** ✅ |

⚠️ ⭐ ⭐ **必须【交叉】** ✅ —— ⭐ FPGA 的 `TX` ⇒ ⭐ USB-TTL 的 `RX` ✅ · ⭐ FPGA 的 `RX` ⇐ ⭐ USB-TTL 的 `TX` ✅
⚠️ ⭐ **还要共地** ✅（⭐ USB-TTL 的 GND ⇒ ⭐ 开发板 GND ✅）

### 🔴 ⭐ 波特率是 **1 Mbaud**（⭐ ⛔ 不是 115200 ✅）

⭐ 依据：⭐ `tb_calib_cmd` 运行时打印的 ⭐ `PARAM_OK=1 (CLK_HZ=50000000 BAUD=1000000 GAP_BYTES=4 BYTE_CLK=500 HEADER=a5 ...)` ✅

| ⭐ 参数 | ⭐ 值 |
|---|---|
| ⭐ 波特率 | ⭐ ⭐ **1000000**（⭐ 1 Mbaud ✅） |
| ⭐ 帧头 | ⭐ `0xA5` ✅ |
| ⭐ 帧间距 | ⭐ `GAP_BYTES = 4` ✅ |

⚠️ ⭐ ⭐ **很多 USB-TTL 默认 115200** ✅ ⇒ ⭐ **必须先改成 1 Mbaud** ✅，⛔ 否则**一个字节都收不到** ✅
📌 ⭐ 廉价 `CH340` 支持 1 Mbaud ✅；⚠️ 而 ⭐ 有些老 `PL2303`/⭐ `CP2102` 在 1 Mbaud 下**不稳** ✅

## ⭐ ② ⭐ **ESP32 专用串口**（⭐ 与调试口**完全独立** ✅）

| ⭐ 信号 | ⭐ FPGA 脚 | ⭐ PMOD0 | ⭐ 方向 |
|---|---|---|---|
| ⭐ `esp_uart_tx_o` | ⭐ **G21** | ⭐ **针 9** | ⭐ 出 → ⭐ ESP32 的 RX ✅ |
| ⭐ `esp_uart_rx_i` | ⭐ **G22** | ⭐ **针 10** | ⭐ 入 ← ⭐ ESP32 的 TX ✅ |

📌 ⭐ ⭐ **所以串口屏和调试【不是】同一个口** ✅ —— ⭐ 屏走 ESP32（⭐ `G21`/`G22` ✅），⭐ 调试走 `D14`/`D15` ✅
⚠️ ⭐ **但两者可以同时用** ✅（⭐ 独立 UART ✅）

## ⭐ ③ ⭐ 用串口做**硬件诊断**（⭐ 直接回答"ADC 是不是饱和" ✅）

| ⭐ 发什么 | ⭐ 看什么 | ⭐ 结论 |
|---|---|---|
| ⭐ ⭐ **`'P'`**（⭐ 位置诊断 ✅） | ⭐ 原始 ADC 码值 | 🔴 ⭐ **全是 4095** ⇒ ⭐ **饱和**（⭐ `VREF` 与 ⭐ 霍尔供电不一致 ✅）<br>🔴 ⭐ **全是 0** ⇒ ⭐ `MISO`/⭐ 片选 有问题 ✅<br>✅ ⭐ 各轴 **2000~2900** 且**互不相同** ⇒ ⭐ ADC 正常 ✅ |
| ⭐ **`'N'`**（⭐ 另一路诊断 ✅） | ⭐ 同上 ✅ | ⭐ 同上 ✅ |

⚠️ ⭐ ⭐ **这是【不用示波器】就能判定"ADC 是否饱和"的最快办法** ✅ —— ⭐ 建议**先做这个** ✅
