hokuu1102/Gowin2026-PolySynth/review/parts/ANVIL-04.part.md

@@@PRIO=P0|SRC=ANVIL-04|ORIG=P0-1|MOD=rtl/w3b/wavetable_bank.v
### 把 10 处硬编码 addr_i[9:0] 参数化，并把契约自检升级成能红的 $fatal
- **位置**：rtl/w3b/wavetable_bank.v:26（端口）、:60/:135/:210/:285/:360/:435/:510/:585/:660/:735（10 处地址）、:850-854（自检）
- **现状**：
```verilog
26:    input wire [$clog2(DEPTH)-1:0] addr_i,          // ← 宽度【跟着 DEPTH 走】
60:        .AD({addr_i[9:0], 4'b0000})                  // ← 但切片【写死 10 bit】
850:    initial begin
851:        if ((TIMBRE_N != 4) || (TIMBRE_W != 2) ||
852:            (DEPTH != 1024) || (SAMPLE_W != 16))
853:            $display("ERROR [wavetable_bank] fixed pROM contract is 4x1024x16");
854:    end
```
- **为什么是问题**：`DEPTH` 在全文只有 2 处被引用（:26 的 `$clog2(DEPTH)` 和 :852 的比较），它不参与任何地址运算。10 处 `.AD()` 里的 `addr_i[9:0]` 把字地址写死成 10 bit = 1024 项（`$clog2(1024)=10`）。Gowin pROM 在 `BIT_WIDTH=16` 时用 **`AD[13:4]`** 作字地址，所以 `{addr_i[9:0], 4'b0000}` 对 `DEPTH=1024` 是正确的 —— **坑不在位序，在于"10"这个字面量**。把 `DEPTH` 改成 2048：端口自动变 11 bit，但地址仍只取低 10 bit ⇒ `addr_i[10]` 被静默丢弃 ⇒ `addr 1024` 与 `addr 0` 命中同一表项。:851-853 的守卫抓不住，三重失效：①它是 `$display` 不是 `$error`/`$fatal` ⇒ vvp 退出码仍是 0；②sim/tb_all.ps1:347 把 ERROR 行只当诊断信息，判据是 :346 的 `(?m)^[ \t]*[^A-Za-z]*FAIL:` 或非零退出码 ⇒ ERROR 行不算失败；③就算算失败，`initial` 块在 Gowin 综合里被丢弃（见 P2-6）⇒ 上板前也无人拦。实测（本报告新增探针，源码
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
