hokuu1102/Gowin2026-PolySynth/model/Keyboard Swidget.stl

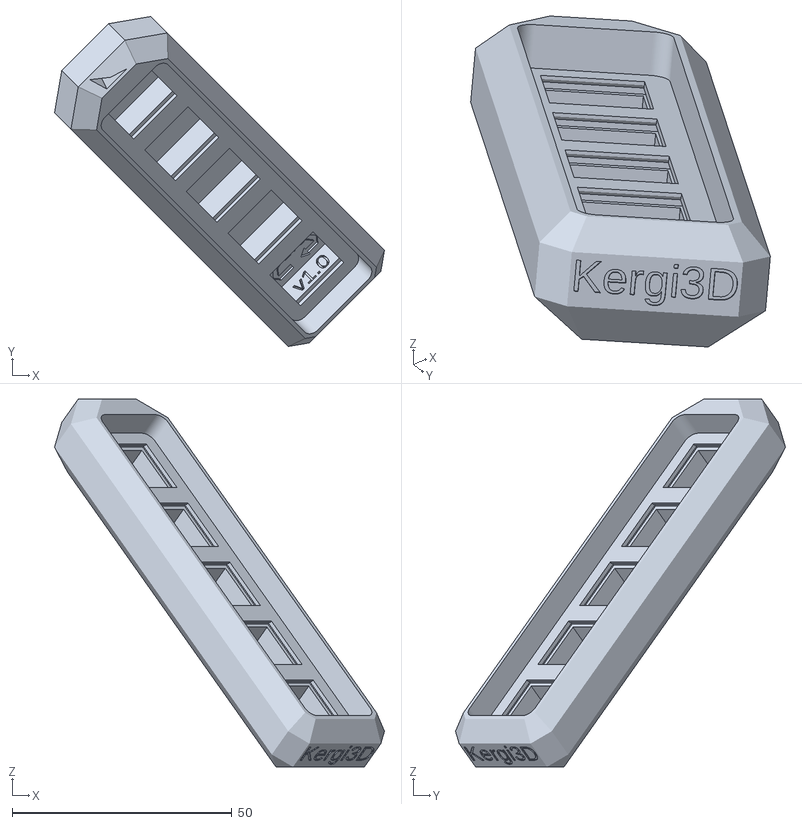
[picture p12: CAD file, 2026-09-13, last stored version]
model/Keyboard Swidget.stl
75.2 x 75.2 x 83.8
