hokuu1102/Gowin2026-PolySynth/model/pcb/左手板单板.step

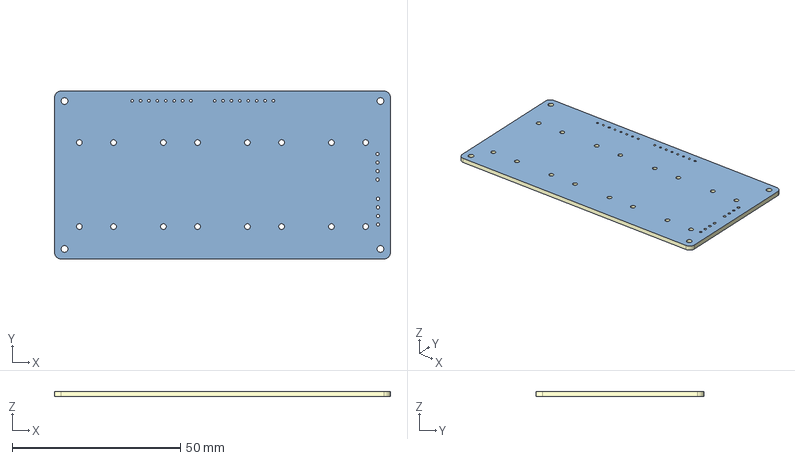
[picture p13: CAD file, 2026-09-15, last stored version]
model/pcb/左手板单板.step
100.0 x 50.0 x 1.60 mm
Board~xgEw
TopCopper~xgEw
BottomCopper~xgEw
TopFpcStiffener~xgEw
BottomFpcStiffener~xgEw
