hokuu1102/Gowin2026-PolySynth/model/step/键帽1.0.STEP

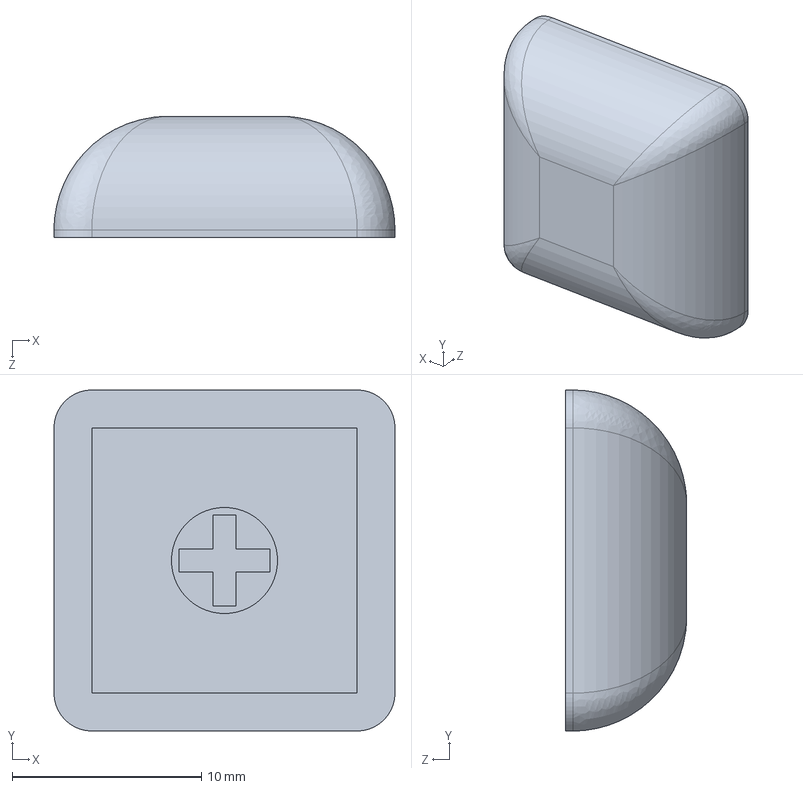
[picture p14: CAD file, 2026-09-13, last stored version]
model/step/键帽1.0.STEP
18.0 x 18.0 x 6.40 mm
