hokuu1102/Gowin2026-PolySynth/model/obj_1_Object_1.stl

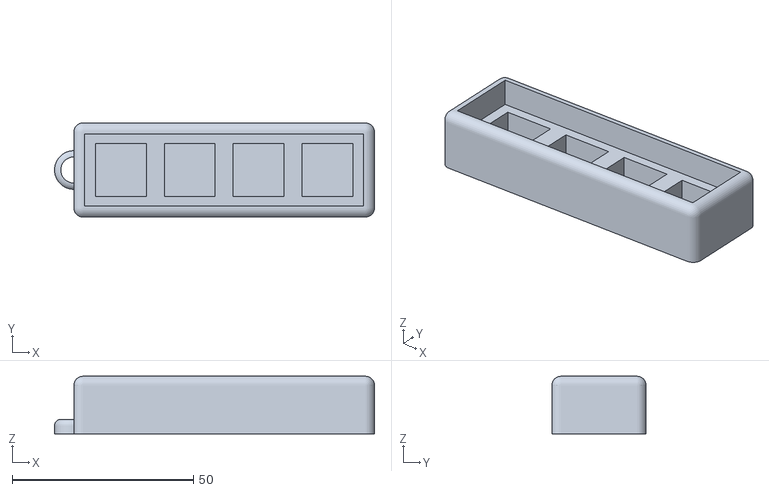
[picture p15: CAD file, 2026-09-13, last stored version]
model/obj_1_Object_1.stl
88.4 x 26.0 x 15.9
