hokuu1102/Gowin2026-PolySynth/model/pcb/左手板.step

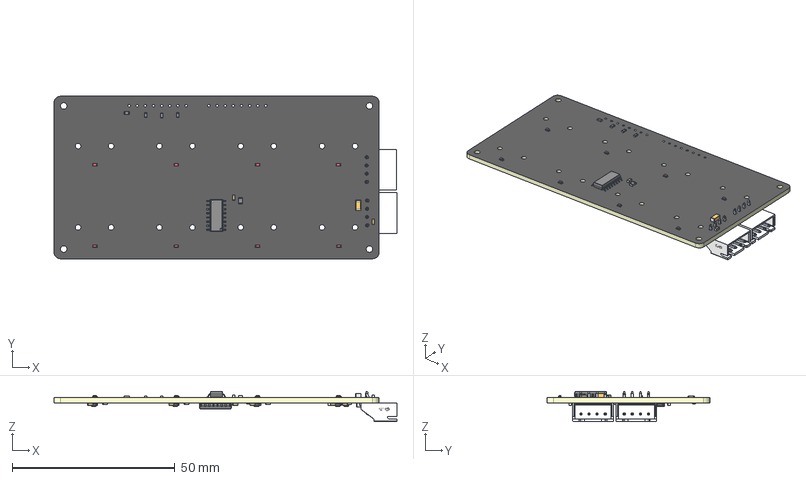
[picture p16: CAD file, 2026-09-15, last stored version]
model/pcb/左手板.step
105.5 x 50.0 x 9.30 mm
Board~LWAX
TopCopper~LWAX
BottomCopper~LWAX
TopFpcStiffener~LWAX
BottomFpcStiffener~LWAX
LED_0603~LED-0603_R~GNUR x 8
C1206~C1206_L3.2-W1.6-H1.3~8qyK
R0603~R0603~SD8G x 6
R0805~R0805_L2.0-W1.3-H0.6~23k2 x 10
C0603~C0603_L1.6-W0.8-H0.8~79tO x 27
C0805~C0805_L2.0-W1.3-H1.3~IaQI
SOT-23-3_L2.9-W1.6-P1.90-LS2.8-BR-CW~SOT-23-3L_L2.9-W1.6-H1.1-LS2.8-P0.95~afig x 8
SOT-23-5_L3.0-W1.7-P0.95-LS2.8-BR~SOT-23-5_L2.9-W1.6-H1.1-LS2.8-P0.95~ZgMQ
CONN-TH_2.54-4P-WZ-D~CONN-TH_2.54-4P-WZ-D~KYjc x 2
SOIC-16_L9.9-W3.9-P1.27-LS6.0-BL~SOIC-16_L9.9-W3.9-H1.8-LS6.0-P1.27~t57E x 2
