hokuu1102/Gowin2026-PolySynth/(list of files, cad)

Other CAD files:
model/键帽1.0.SLDPRT
