hokuu1102/Gowin2026-PolySynth/evidence/w1_3/adsr_build.txt

W1-3 / T9 independent ADSR evidence
date=2026-09-20
owner=yi
status=PASS
scope=single-voice ADSR plus 32-voice envelope bank
clock_domain=50 MHz system clock; sample_tick is a clock enable
single_voice_behavior=PASS attack decay sustain release
velocity_scaled_peak=PASS
late_velocity_correction=IMPLEMENTED; dedicated L5 acceptance not run
retrigger_during_release=IMPLEMENTED; dedicated voice integration acceptance not run
per_voice_independence=PASS with staggered gates and different velocities
full_regression=19/19 PASS
gowin_tool=V1.9.12.03 x64
gowin_synthesis=PASS
gowin_compiled_adsr=YES
gowin_compiled_envelope_bank=YES
poly_target=32
independent_adsr_instances=32
registers_per_adsr=19
envelope_bank_registers=608
envelope_bank_alu=1023
envelope_bank_lut=5716
envelope_bank_dsp=0
synth_check_total_logic=6900/59904 (12 percent)
synth_check_total_registers=700/60780 (2 percent)
synth_check_bsram=1/118
default_attack_step=669 (about 2.0 ms to maximum peak)
default_decay_step=4 (about 250 ms from maximum peak to 25 percent sustain)
default_sustain_q8=64 (25 percent of velocity-scaled peak)
default_release_step=2 (about 167 ms from maximum sustain to zero)
board_validation=NOT_APPLICABLE for T9 functional acceptance
dds_adsr_i2s_integration=NOT_RUN; tracked by T10
