hokuu1102/Gowin2026-PolySynth/evidence/w1_2/wavetable_tone_build.txt

W1-2 wavetable tone integration evidence
date=2026-09-19
tool=Gowin EDA V1.9.12.03 x64
device=GW5AT-LV60PG484AC2/I1
top=wavetable_tone_top
result=PASS
scope_of_pass=RTL simulation and Gowin build only
board_available=NO
board_programming=NOT_RUN
physical_audio_check=NOT_RUN
oscilloscope_check=NOT_RUN
board_validation=DEFERRED until Tang Mega 60K Dock arrives
full_regression=17/17 PASS
core_phase_continuity=PASS
behavioral_top_simulation=PASS
vendor_wrapper_top_simulation=PASS
decoded_tone_frequency_hz=439 integer estimate (target 440)
decoded_period_samples=111
bclk_period_system_clocks=16
lrclk_period_system_clocks=1024
pa_falling_edges=1
synthesis=PASS
place_and_route=PASS
bitstream_generation=PASS
setup_violated_endpoints=0
hold_violated_endpoints=0
actual_fmax_mhz=56.478
constraint_mhz=50.000
bsram_total=1
prom_total=1
pin_clk=V22
pin_rst_n=AA13
pin_HP_BCK=Y17
pin_HP_WS=AB17
pin_HP_DIN=AA16
pin_PA_EN_n=AB16
pin_led_heartbeat=T18
bitstream=bringup/wavetable_tone/impl/pnr/wavetable_tone.fs
known_warning=PR1014 generic clock routing; STA still passes at 50 MHz with 56.478 MHz Actual Fmax
