hokuu1102/Gowin2026-PolySynth/docs/releases/guide-timing-20261102/README.md

# 指引时序优化：本地验收记录

采用第5候选`trial05-local-metadata-p1`，实际编译源码为`470be0e326f7a1c5f9c553d093d0bb26891c2d33`。本目录提交只整理验收证据，不再修改RTL或编译配置。工作频率仍为50MHz，未推送远端，实机验收待完成。

## 保留版与结果

原版固定在本地标签`archive/guide-fix-50m905-local-20261101`，提交`97a50966d71b775e086177936b7bec7b50b8d601`。原分支、工作区和原烧录文件均保留。

|项目|原合格版|本候选|
|---|---:|---:|
|Fmax|50.905MHz|52.015MHz|
|实际50MHz Setup余量|+0.356ns|+0.775ns|
|Hold最低余量|+0.178ns|+0.186ns|
|Recovery最低余量|+0.284ns|+0.250ns|
|Removal最低余量|+0.203ns|+0.203ns|
|16.4ns优化预算最差Setup|-3.244ns|-2.825ns|
|16.4ns预算未满足端点|3248|452|
|16.4ns预算Setup TNS|-3340.042ns|-351.265ns|

原时序验收脚本退出码0。Fmax增加1.110MHz，实际50MHz Setup余量增加0.419ns；不宣称更严的16.4ns优化预算已全部满足。

## 实现与功能保持

将已有的一拍显示采样放在音高查表之后，并把同拍采样的轴号、原音符身份和映射键号复制到各8槽组。每组匹配与元数据写入使用本组副本，降低单个寄存器跨64槽的扇出；OFF和空槽选择仍保持原最低槽规则。

总显示延迟仍为一拍20ns，没有增加处理周期。保留64个身份槽、32位重复计数、ON/OFF配对、控制快照、逐键50ms提示及重触发行为。声音、Loop、串口协议、波形/效果数据、工作频率、IO约束和验收脚本均未修改。

综合寄存器由26568增至26671，净增加103个，确认复制未被合并；LUT由43156变为43153，ALU、DSP和BSRAM不变，BSRAM仍为104块。没有通过缩减功能或存储容量换取时序。

## 验证与试验取舍

本轮9项受影响检查全部通过，未重跑全量回归。新增改前/改后逐拍对照覆盖1、3、9、64、65槽，共11280拍，比较全部公开输出及完整账本；覆盖容量拒绝、重复身份、32位计数边界、随机模式/变调、复位和超时。参考模型已与改前提交`8ffd0c23940d4eab7a928e3fa601278dd3439dda`规范化内容核对，仅模块名不同。故意把复制轴号改错的负对照被检出。

其余检查覆盖默认直通模式的任意状态等价、漏灯相位、顶层控制快照、实际LED串行锁存/OE、多音高、指引轨过滤、灌谱及键盘鼓隔离。原始“声音正确但灯不闪”场景重放通过。仍需用原漏灯曲目、同音重奏、和弦、模式/变调和Loop进行上板验收。

第1、2、4候选分别为48.315、50.012、46.574MHz，均未优于保留版；第3候选因304条未布通网络失败，没有烧录件。第6候选使用与第5候选相同的RTL比较另一布局选项，在已找到并验证合格改善实现后停止，未完成比较，不计作通过。详见交付目录的试验记录。

## 交付对应

目录：`D:/ChatGPT/Outputs/FPGA-guide-timing-20261101/delivery/`。

- 烧录件：`Gowin2026-51-HMI-guide-timing-opt-50MHz-20261102.fs`
- SHA256：`4a02c537225732897088bea5b1898b016e868dfec7031647d6454aa81091585c`
- 源码包：`FPGA-guide-timing-opt-source-20261102.zip`

交付目录包含原生STA、路径与资源报告、编译输入哈希、测试日志、源码差异、试验对比和完整校验和。源码ZIP逐字节保存实际编译输入；本目录文档提交后的RTL与实际编译源码保持一致。
