hokuu1102/Gowin2026-PolySynth/esp32/evidence/鼓与旋律分离-20261016/运行输出-check_guide.js.txt

======================================================================================
引导模式核对：StJamesInfirmary-funk-测试曲.mid
  被测页面：C:\Users\hokuu\Desktop\FPGA\FPGA2026-esp32\esp32\tools\score_studio.html
    脚本块指纹 sha256[0:12] = 38397fea3819   脚本块 3914 行 · 文件 234345 字节 · 改动时间 2026-10-16T06:40:58.308Z
    （该文件正由他人改动 ⇒ 指纹用来对齐「这份报告判的是哪一版」）
======================================================================================

【零】测试钩子与输入
  测试钩子：使用页面自带的 __setGuide()
  解析：division = 960 · PPQN = 960 · 缩放 SCALE = 1 · 轨数 = 5 · tempo 点 = 2
  页面常数：BAR_TICK = 3840 · DRUM_DUR_TICK = 480 · DRUM_AXIS_OF = {"kick":12,"snare":13,"hihat":14,"tom":15}
  独立期望：小节 = 3840 · 同件间隔下限 = 480 · 轴 = {"kick":12,"snare":13,"hihat":14,"tom":15} · beat 音型 = [["kick",0],["tom",960],["snare",1920],["tom",2880]] + 踩镲 [0,960,1920,2880]
  引导轨 = 轨 0「Bass」（非鼓、音符最多：53 个音）
  谱面长度 = 38400 tick => 小节数 = 10（页面 metEnd = 38400）
  UI id（报告项，非判据）：gd_on/gd_track/gd_met/gd_style/gd_sum 全在

  轨表（字总数 / bit6=1 均取【主产物：引导 + 节拍器】）
  轨  | 轨名        | 音符(on) | 字总数 | bit6=1 | 角色
  ----|-------------|----------|--------|--------|----------------
  0   | Bass        | 53       | 106    | 106    | 引导轨
  1   | Guitar      | 36       | 72     | 0      | 背景
  2   | Piano       | 36       | 72     | 0      | 背景
  3   | Pad         | 32       | 64     | 0      | 背景
  4   | Drum        | 130      | 260    | 0      | 鼓
  -1  | （公共事件）      | -        | 2      | 0      | 公共
  -2  | （节拍器）       | -        | 160    | 0      | 节拍器

【一】判据（反控不红 = 该判据可能是恒真的假绿）
  [OK] ① 引导轨的字 bit6=1，且数量 = 音符数×2（on/off 成对）               置位 106 字 / 期望 106
       音符(on) 53 × 2 = 106 · 置位 106（on 53 / off 53）· 用到轴 0,1
       该轨 note 事件 106 个（on 53 + off 53）= 该轨字总数，二者一致
  [OK] ② 其余轨（含鼓轨与公共事件）的字 bit6=0                            轨-1 0/2 · 轨4 0/260 · 轨-2 0/160 · 轨1 0/72 · 轨3 0/64 · 轨2 0/72
       反控 把轨 -1 的下标 0 那个字 bit6 置 1 -> 判据② 变红（符合预期）
  [OK] ③ 节拍器落点与数量正确（beat 每小节 8 下；避让与否随鼓声档）                 生成器 80/80 下 · met 档（不避让）响 80 + 跳过 0 = 10×8 · both 档（避让）响 31 + 跳过 49
       生成器单测（buildMetronome(tickMax, {}) 不避让）：{"kick":10,"tom":20,"snare":10,"hihat":40} · 期望 kick 10 / tom 20 / snare 10 / hihat 40 = 80 下 · 落点逐点命中独立音型
       页面新规则（2026-10-16）：guideOn && guideDrum==="met" ⇒ 谱面鼓轨会被丢掉 ⇒ 节拍器【不再避让】（否则会在本该响的拍点上留洞）；track / both 档才按同一件 >= 480 避让。
         met 档：响 80 + 跳过 0 = 80（不避让 ⇒ 跳过必须为 0，落点必须全响）
         both 档：响 31 + 跳过 49 = 80（避让 ⇒ 跳过数与独立重算一致）
         （为什么还要单测生成器：避让档里落点被跳掉大半，光看产物验不出每件每小节几下 —— 那是判据③的原话。）
       逐件（met 档）：响 {"kick":10,"hihat":40,"tom":20,"snare":10} · 跳过 0 下（每件上限 kick 10/snare 10/tom 20/hihat 40）
       第 1 小节落点（8 个期望点）：
         tick 0      偏移 0    hihat  已响
         tick 0      偏移 0    kick   已响
         tick 960    偏移 960  hihat  已响
         tick 960    偏移 960  tom    已响
         tick 1920   偏移 1920 hihat  已响
         tick 1920   偏移 1920 snare  已响
         tick 2880   偏移 2880 hihat  已响
         tick 2880   偏移 2880 tom    已响
       第 2 小节落点（8 个期望点）：
         tick 3840   偏移 0    hihat  已响
         tick 3840   偏移 0    kick   已响
         tick 4800   偏移 960  hihat  已响
         tick 4800   偏移 960  tom    已响
         tick 5760   偏移 1920 hihat  已响
         tick 5760   偏移 1920 snare  已响
         tick 6720   偏移 2880 hihat  已响
         tick 6720   偏移 2880 tom    已响
       反控 抽掉 1 个节拍器落点 -> 判据③ 变红（符合预期）
       反控 把第 1 个落点挪到音型外（+120 tick）-> 判据③ 变红（符合预期）
       反控 把小节数多报 1（11）-> 判据③生成器 变红（符合预期）：on 数 80 != 11×8 = 88
       反控 音型换 four、却按 beat 的期望判 -> 判据③生成器 变红（符合预期）：kick 多重性不对：20 != 10（每小节 1 下）
       反控 把 met 档（不避让）按「该避让」去判 -> 判据③ 变红（符合预期）：有 49 个落点与谱面同件鼓间隔 < 480 却没跳过：tick 0 kick（谱面同件在 0） | tick 0 hihat（谱面同件在 0） | tick 960 hihat（谱面同件在 960）
       反控 把 both 档（避让，跳了 49 下）按「不避让」去判 -> 判据③ 变红（符合预期）：该响没响且无正当理由：第 1 小节 偏移 0 的 kick（tick 0）——本档不避让（引导开 + 鼓声=节拍器，谱面鼓会被丢掉），落点必须全响
  [OK] ④ 同一件鼓相邻落点间隔 >= 480 tick（方案 B，跨件不限）                 met 档可见字：最小 960 · 76 个间隔 · 违规 0 ｜ both 档：最小 480 · 157 个间隔 · 违规 0
       对象 = visibleWords（所见即所灌），不是全量字表：全量里 met 档的谱面鼓字【不会发下去】，拿它去量 480 只会量出一堆不存在的碰撞。
       met 档逐件：kick 10下/最小3840 · hihat 40下/最小960 · tom 20下/最小1920 · snare 10下/最小3840
       both 档逐件：kick 30下/最小480 · hihat 78下/最小480 · snare 29下/最小960 · tom 24下/最小480
       （报告）全量字表里 met 档的鼓轴落点 210 个（节拍器 80 + 谱面鼓 130）—— 它们不再要求互不碰撞
       反控 在 kick 的 0 之后 240 tick 插一下 -> 判据④ 变红（符合预期，报 1 处）
       反控 在 snare 附近（tick 3120，离所有 kick 都 >= 480）插一个【kick】（跨件）-> 判据④ 仍然绿（符合预期：方案 B 只约束同一件）
       反控 在 snare 的 960 之后 240 tick 插一个【snare】（同件）-> 判据④ 变红（符合预期，报 1 处）
  [OK] ⑤ 全曲 bit6=1 的字数 > 0（非空洞）                            实际置位 106 字 · 页面 guideWords 账 = 106
       反控 关掉引导（guideOn=false）-> 置位 0 字，判据⑤ 变红（符合预期）
  [OK] ⑥ 反向证伪：全置位/全零/错轨 三种反控下判据①必须红                        全置位 红 · 全零 红 · 错轨 红
       结构不变量：每轨轮流置位产物的（清掉 bit6 后）字序列与主产物逐字相同 = true（不相同则反控本身无效）
       每轨轮流置位得到的置位数：轨0=106 · 轨1=72 · 轨2=72 · 轨3=64 · 轨4=0
       反控 a 全置位（并集）-> 判据① 变红（符合预期）：置位 314 字 vs 期望 106（有 208 个置位字的源轨不是引导轨（例：下标 38 的源轨 = 1，引导轨 = 0））
       反控 b 全零（关引导）-> 判据① 变红（符合预期）：置位 0 字 vs 期望 106
       反控 c 错轨：把轨 1「Guitar」当引导轨，却按轨 2「Piano」的预期判（两轨音符数都是 36，数量对得上，只能靠轨身份抓）-> 判据① 变红（符合预期）：有 72 个置位字的源轨不是引导轨（例：下标 38 的源轨 = 1，引导轨 = 2）
  [OK] ⑦ 回读：unpackWord 解回的 guide 位与预期一致                    解回置位 106 字 / 预期 106
       字段逐项比对（页面 unpackWord vs 独立位提取）：不一致 0 字 · packWord 往返不符 0 字 · 独立编码器往返不符 0 字 · 8 字节往返不符 0 字
         （独立位提取与独立编码器都【不调页面的 unpackWord/packWord】——覆盖 64 位：tick20+inc21+axis4+vel8+kind2+timbre2+guide1+isDrum1+note5 5，⛔ 不是拿被验者验自己）
       磁盘产物 events.hex：576 行 · 非法行 0 · guide 位与原始 bit6 不符 0 行 · 该文件里 bit6=1 的字 0 个 · 与「无引导无节拍器」产物逐字相同 = true · 与主产物相同 = false
         （该 hex 是引导模式之前生成的产物，bit6 全 0 属正常；这里验的是它的解码一致性）
       反控 比对器自检：把 axis 改错 1 -> 报不一致字段 ["axis"]（符合预期）
       反控 把下标 0（源轨 -1）那个字的 bit6 置 1 -> 判据⑦ 变红（符合预期）：解回置位 107 vs 预期 106
  [OK] ⑧ UI 填充路径不崩 + 下拉内容正确（buildTrackPicker）              不抛异常 · 可选轨 option 4/4 · selected 跟着状态走=true
       gd_track 的 option 共 5 个 = 1 个「（不选）」占位（value=""）+ 4 条非鼓轨；鼓轨不出现
         可选轨 value = [0,1,2,3] · 期望 [0,1,2,3]（Bass·106事件 / Guitar·72事件 / Piano·72事件 / Pad·64事件）
         引导轨 0 那一项：<option value="0" selected>
       gd_sum.textContent = "引导轨 「Bass」 · 保留其他轨 · 鼓声 两者 · 仅指引 106 字 · 节拍器 80 下 · 会灌 736 字"
       反控 把引导轨换成轨 1「Guitar」再填充 -> 轨 1 带 selected、原引导轨 0 撤掉 selected = true（符合预期：selected 跟着状态走）

【一之补】新增接口（引导范围 / 鼓声来源 / 所见即所灌）
  页面函数：guideScopedWords ✓ · visibleWords ✓ · wordsForSelected ✓ · buildPayload ✓
  页面状态：guideScope = "all" · guideDrum = "met"（默认应为 "all" / "met"）
  节拍器源轨号：独立期望 -2 · 产物里节拍器字的源轨集合 = [-2]
  UI id（报告项，非判据）：gd_scope/gd_drum 全在
  [OK] ⑨ solo：只剩 tempo + 引导轨 + 节拍器（背景轨一个不剩）                可见 268 字 / 独立重算 268 字 · 引导轨 106 字（all 时 106）
       逐字比对（页面的 visibleWords vs 独立重算的 keep 子序列）：完全一致
       可见字的源轨分布：轨-2=160(节拍器) · 轨-1=2(tempo/公共) · 轨0=106(引导轨)
       背景旋律轨（非鼓、非引导）：轨1,轨2,轨3 ⇒ 各 0 字（轨1=0 · 轨2=0 · 轨3=0）
       反控 把 all 档的结果当作 solo 的产物来判 -> 判据⑨ 变红（符合预期）：字数 476 != 独立重算 268
  [OK] ⑩ all：背景旋律轨的字还在（逐轨字数与全量一致）                          可见 476 字 · 背景轨 轨1=72 · 轨2=72 · 轨3=64
       背景旋律轨逐轨：全量字数 vs 可见字数 —— 轨1 72/72 · 轨2 72/72 · 轨3 64/64
       反控 把 solo 档的结果当作 all 的产物来判 -> 判据⑩ 变红（符合预期）：字数 268 != 独立重算 476
  [OK] ⑪ guideDrum 三档：met / track / both 的鼓声来源各自正确         met 鼓轴字 160（节拍器 160 · 谱面鼓 260）· track 鼓轴字 260（节拍器 62 · 谱面鼓 260）· both 鼓轴字 322（节拍器 62 + 谱面鼓 260）
       谱面鼓轨下标 = [4] · 期望：met ⇒ 可见鼓轴字 == 节拍器字数（谱面鼓一个不剩）；track ⇒ 可见鼓轴字 == 谱面鼓轨字数（节拍器一个不剩）；both ⇒ 两者之和
       三档的可见字数：met 476 · track 576 · both 638 · bit6=1 字数 106/106/106（都须 = 引导轨音符×2 = 106）· tempo 字数 2/2/2（都须 = 2）
       节拍器账（页面 conv.metCount / metSkipped）：met 档 80/0（不避让 ⇒ 跳过必须 0）· track 档 31/49（避让，但节拍器字不发下去）· both 档 31/49（避让）
       反控 把 met 档的产物当作 track 档来判 -> 判据⑪ 变红（符合预期）：track 档：字数 476 != 独立重算 576
  [OK] ⑫ 所见即所灌：payload 结构反推的字数 == visibleWords 长度          可见 476 字 / 全量 736 字 · payload 4329 字节（反推 476 · 总数帧 476）
       payload 结构 = 4 复位帧 + 1 总数帧 + N 事件帧（每帧 9 字节）⇒ 45 + 9×476 = 4329 字节（实测 4329）
       tickMax：buildScore(可见字) = 38400 <= buildScore(全量) = 38400 ⇒ true
       反控 把总数帧里写的 N 改成 477 -> 判据⑫ 变红（符合预期）：总数帧里写的 N = 477 != visibleWords 长度 476
       反控 payload 比 visibleWords 多 1 个事件帧 -> 判据⑫ 变红（符合预期）：payload 长度 4338 != 4×9 + 9 + 476×9 = 4329
  [OK] ⑬ 非空洞 + 反向证伪：solo→all 必须变长；guideOn=false 必须原样返回     solo 268 -> all 476（变长 208，应裁 208）· guideOn=false 原样 638/638 · 引导关+节拍器关 原样 576/576
       变长量必须 > 0（相等 ⇒ 红）· 且必须等于独立重算的应裁量 208（背景旋律轨 + 谱面鼓轨的字数）
       guideOn=false 时 visibleWords 必须与 conv.words 逐字相同（关掉引导模式与以前逐字节相同）——两档都验：节拍器开（638 字）与节拍器关（576 字）
       反控 把 all 的结果同时当作 solo 与 all -> 判据⑬ 变红（符合预期）：all 的字数 476 没有比 solo 的 476 长（裁剪没在起作用 ⇒ 判据⑬ 红）
  [OK] ⑭ 选轨 × 引导裁剪：只选 [引导轨, 鼓轨] 时 visibleWords 仍然正确        子集+met 可见 268 字（bit6 106 / 鼓轴 160）· 子集+track 可见 368 字（鼓轴 260） · 吉他 idx1 子集 234 字
       🔴 抓的坑：把 wordsForSelected() 的输出再喂给 guideScopedWords()（后者按下标读 conv.evTrack）⇒ 下标错位 ⇒ 实测「引导轨置位数从 72 掉到 45、鼓轴字数变 185」。
         只选 [引导轨 0, 鼓轨 4] + met：可见 268 字 · bit6 106（期望 106 = 引导轨音符×2）· 鼓轴 160（期望 160 = 10 小节 × 8 下 × 2，met 档不避让）
         只选子集 + track：可见 368 字 · 鼓轴 260（期望 = 谱面鼓轨字数）
       旧口径（wordsForSelected 的输出再喂 guideScopedWords）得到的字数 528 vs 页面 visibleWords 的 268 ⇒ 与页面结果不同 = true（不同才对：这正是那个坑）
       guideScopedWords 的长度守卫：喂子集（528 / 736）⇒ 原样返回 = true（⛔ 不静默错位）
       用户自测那一组（引导轨 = 吉他 idx1，只选 [1, 鼓轨]，scope=all / drum=met）：可见 234 = tempo 2 + 引导轨 72 + 节拍器 160（期望 234 = 2 + 72 + 160）
       反控 把全选（scope=all/met）的产物当作「只选[引导轨,鼓轨]」来判 -> 判据⑭ 变红（符合预期）：旧口径（wordsForSelected 的输出再喂 guideScopedWords）与 visibleWords 结果相同 —— 说明这一组输入下两种口径恰好一致（全选时就是这样；只有选了子集才会分叉）
  [OK] ⑮ 鼓/旋律分离：鼓 inc 全 0 · 旋律 inc 全非 0 · is_drum=0 无轴 12..15全量：鼓 420 / 旋律 314 · 可见：is_drum 字 160 == 鼓轴字 160 · 鼓 inc≠0 0 · 旋律 inc=0 0 · 旋律落鼓轴 0
       全量产物（2 个 tempo）逐条扫：420 条鼓 / 314 条旋律
       可见字（visibleWords，476 字）逐条扫：is_drum=1 的字 160 条，其中 inc≠0 的 0 条；轴落 12..15 的字 160 条（新口径下这两个数必须相等 —— is_drum=0 的字一条都不许占鼓轴）
  [OK] ⑯ 鼓 ON/OFF 按 (axis,drum_type) 全配对（OFF 也带 is_drum=1 与同一 drum_type）+ 鼓 note_off5=0ON 210 / OFF 210 · 未闭合 0 · 无主 OFF 0 · 鼓段上漏标 is_drum 的 OFF 0 · note_off5≠0 的鼓 0
       逐件 ON/OFF 数（按 drum_type）：kick 40/40 · snare 29/29 · hihat 116/116 · tom 25/25（手册点名的死线：OFF 漏带 is_drum/drum_type ⇒ 鼓 voice 永久 held ⇒ 保留池耗尽）
  [OK] ⑰ 鼓件按 drum_type 认件：四件齐全 + drum_type↔axis 一一对应 + 页面表与手册一致四件计数 kick=80 · snare=58 · hihat=232 · tom=50 · 轴 12/13/14/15
       对照表（手册 §二/§4.3，独立写死）：kick=drum_type0/轴12 · snare=drum_type1/轴13 · hihat=drum_type2/轴14 · tom=drum_type3/轴15
       反控 手造一条 is_drum=1 且 inc≠0 的字 -> 判据⑮ 变红（符合预期）：鼓事件 inc 非 0：1 条（硬检查②）（字 736 inc=37796）
       反控 手造一条 is_drum=0 且 inc=0 的旋律字 -> 判据⑮ 变红（符合预期）：旋律事件 inc=0：1 条（字 736）
       反控 手造一条 is_drum=0 且轴=13 的字 -> 判据⑮ 变红（符合预期）：is_drum=0 的事件轴号落 12..15：1 条（§7.3-1）（字 736 axis=13）
       反控 手造一条 kind=2（tempo）却 is_drum=1 的字 -> 判据⑮ 变红（符合预期）：tempo 事件（kind=2）的 is_drum 必须为 0（字 736）
       反控 把一条鼓 OFF 的 is_drum 位清 0（ON/OFF 不同步）-> 判据⑯ 变红（符合预期）：鼓 ON 没配到同 (axis, drum_type) 的 OFF：1 条（挂音、耗尽鼓池）
       反控 把一条鼓 OFF 的 drum_type 改成 snare(1)（与 ON 不一致）-> 判据⑯ 变红（符合预期）：鼓 ON 没配到同 (axis, drum_type) 的 OFF：1 条（挂音、耗尽鼓池）
       反控 拔掉一条鼓 OFF -> 判据⑯ 变红（符合预期）：鼓 ON 没配到同 (axis, drum_type) 的 OFF：1 条（挂音、耗尽鼓池）
       反控 把一条鼓事件的 note_off5 置 7 -> 判据⑯ 变红（符合预期）：is_drum=1 的事件 note_off5 非 0：1 条（鼓没有音高）
       反控 把一条鼓事件的 drum_type 改成 hihat(2)（轴仍是 12）-> 判据⑰ 变红（符合预期）：drum_type 与轴不是一一对应：2 处（drum_type 2 出现在轴 12 | 字 6 drum_type=2 轴=12 != 14）

【二】其它音型自检（报告项，不计入判据）
  音型 beat （1底鼓/2嗵鼓/3军鼓/4嗵鼓 + 每拍踩镲）：响 80 + 跳过 0 = 80（期望 10×8 = 80）· 逐件 {"kick":10,"hihat":40,"tom":20,"snare":10}
  音型 off  （同上，踩镲落反拍）：响 80 + 跳过 0 = 80（期望 10×8 = 80）· 逐件 {"kick":10,"hihat":40,"tom":20,"snare":10}
  音型 four （踩镲每拍 + 底鼓1/3 + 军鼓2/4）：响 80 + 跳过 0 = 80（期望 10×8 = 80）· 逐件 {"kick":20,"hihat":40,"snare":20}

  结论：全部通过（17 项）
