hokuu1102/Gowin2026-PolySynth/evidence/h5/build-initial-c2-hold11/main-timing-summary.txt

Report Title | Timing Analysis Report
Design File | C:\Users\cyx\Documents\ChatGPT\FPGA\Gowin2026-PolySynth-t31b-main\impl\gwsynthesis\Gowin2026.vg
Physical Constraints File | C:\Users\cyx\Documents\ChatGPT\FPGA\Gowin2026-PolySynth-t31b-main\constr\top.cst
Timing Constraint File | C:\Users\cyx\Documents\ChatGPT\FPGA\Gowin2026-PolySynth-t31b-main\constr\top.sdc
Tool Version | V1.9.12.03 (64-bit)
Part Number | GW5AT-LV60PG484AC2/I1
Device | GW5AT-60
Device Version | B
Created Time | Thu Oct 1 18:41:52 2026
Legal Announcement | Copyright (C)2014-2026 Gowin Semiconductor Corporation. All rights reserved.
Setup Delay Model | Slow 0.93V 0C C2/I1
Hold Delay Model | Fast 0.975V 85C C2/I1
Numbers of Paths Analyzed | 49751
Numbers of Endpoints Analyzed | 50625
Numbers of Falling Endpoints | 4
Numbers of Setup Violated Endpoints | 0
Numbers of Hold Violated Endpoints | 11
NO. | Clock Name | Type | Period | Frequency(MHz) | Rise | Fall | Source | Master | Objects
1 | clk_sys | Base | 20.000 | 50.000 0.000 | 10.000 |  |  | clk
2 | serial_clk | Generated | 8.000 | 125.000 0.000 | 4.000 | clk | clk_sys | u_hdmi/u_clk/u_pll/CLKOUT0
3 | pixel_clk | Generated | 40.000 | 25.000 0.000 | 20.000 | clk | clk_sys | u_hdmi/u_clk/u_pll/CLKOUT1
NO. | Clock Name | Constraint | Actual Fmax | Logic Level | Entity
1 | clk_sys | 50.000(MHz) | 61.651(MHz) | 10 | TOP
2 | pixel_clk | 25.000(MHz) | 143.572(MHz) | 9 | TOP
Clock Name | Analysis Type | Endpoints TNS | Number of Endpoints
clk_sys | Setup | 0.000 | 0
clk_sys | Hold | 0.000 | 0
serial_clk | Setup | 0.000 | 0
serial_clk | Hold | 0.000 | 0
pixel_clk | Setup | 0.000 | 0
pixel_clk | Hold | 0.000 | 0
PA1019 count in fresh full build log: 0
PASS clk_sys: Fmax=61.651 MHz; frequency headroom over 50 MHz=23.302%; gate >=51.5 MHz AND >=3%
PASS pixel_clk: Fmax=143.572 MHz; frequency headroom over 25 MHz=474.288%; gate >=51.5 MHz AND >=3%
Bitstream SHA256: be836c2ec5fd63835e2f4fcc2afab31adae30cb59884a6ba1f1ea9db0d17def8
E3 FAIL
