hokuu1102/Gowin2026-PolySynth/evidence/h5/build-c1-default-margin-fail/main-pins.html

- Pin Messages
- Pin Details
  - Pinout by Port Name
  - All Package Pins

# Pin Messages

Report Title | Pin Report
Design File | C:\Users\cyx\Documents\ChatGPT\FPGA\Gowin2026-PolySynth-t31b-main\impl\gwsynthesis\Gowin2026.vg
Physical Constraints File | C:\Users\cyx\Documents\ChatGPT\FPGA\Gowin2026-PolySynth-t31b-main\constr\top.cst
Timing Constraints File | C:\Users\cyx\Documents\ChatGPT\FPGA\Gowin2026-PolySynth-t31b-main\constr\top.sdc
Tool Version | V1.9.12.03 (64-bit)
Part Number | GW5AT-LV60PG484AC1/I0
Device | GW5AT-60
Device Version | B
Created Time | Thu Oct 1 19:00:07 2026
Legal Announcement | Copyright (C)2014-2026 Gowin Semiconductor Corporation. All rights reserved.

# Pin Details

## Pinout by Port Name:

Port Name | Diff Pair | Loc./Bank | Constraint | Dir. | Site | CFG | IO Type | Drive | Pull Mode | PCI Clamp | Hysteresis | Open Drain | Slew Rate | Vref | Single Resistor | Diff Resistor | BankVccio | Pull Strength | Ctle | Threshold Offset | ADC_INPUT
clk | - | V22/7 | Y | in | IOB117[B] | EMCCLK | LVCMOS33 | OFF | NONE | OFF | ON | OFF | SLOW | OFF | OFF | OFF | 3.3 | MEDIUM | NONE | OFF | bus4
rst_n | - | AA13/9 | Y | in | IOB54[B] | - | LVCMOS15 | OFF | UP | OFF | ON | OFF | SLOW | OFF | OFF | OFF | 1.5 | MEDIUM | NONE | OFF | bus4
timbre_btn_i | - | AB13/9 | Y | in | IOB54[A] | - | LVCMOS15 | OFF | UP | OFF | ON | OFF | SLOW | OFF | OFF | OFF | 1.5 | MEDIUM | NONE | OFF | bus4
pluck_up_i | - | E21/2 | Y | in | IOT138[A] | - | LVCMOS33 | OFF | UP | OFF | ON | OFF | SLOW | OFF | OFF | OFF | 3.3 | MEDIUM | NONE | OFF | bus0
pluck_down_i | - | D21/2 | Y | in | IOT138[B] | - | LVCMOS33 | OFF | UP | OFF | ON | OFF | SLOW | OFF | OFF | OFF | 3.3 | MEDIUM | NONE | OFF | bus0
spi_miso[0] | - | C15/1 | Y | in | IOT85[B] | - | LVCMOS33 | OFF | UP | OFF | ON | OFF | SLOW | OFF | OFF | OFF | 3.3 | MEDIUM | NONE | OFF | -
spi_miso[1] | - | B13/1 | Y | in | IOT93[B] | - | LVCMOS33 | OFF | UP | OFF | ON | OFF | SLOW | OFF | OFF | OFF | 3.3 | MEDIUM | NONE | OFF | bus2
spi_miso[2] | - | A14/1 | Y | in | IOT95[B] | - | LVCMOS33 | OFF | UP | OFF | ON | OFF | SLOW | OFF | OFF | OFF | 3.3 | MEDIUM | NONE | OFF | bus2
spi_miso[3] | - | B16/1 | Y | in | IOT97[B] | - | LVCMOS33 | OFF | UP | OFF | ON | OFF | SLOW | OFF | OFF | OFF | 3.3 | MEDIUM | NONE | OFF | bus2
spi_miso[4] | - | A16/1 | Y | in | IOT99[B] | - | LVCMOS33 | OFF | UP | OFF | ON | OFF | SLOW | OFF | OFF | OFF | 3.3 | MEDIUM | NONE | OFF | bus2
spi_miso[5] | - | A20/2 | Y | in | IOT122[B] | - | LVCMOS33 | OFF | UP | OFF | ON | OFF | SLOW | OFF | OFF | OFF | 3.3 | MEDIUM | NONE | OFF | bus1
uart_rx | - | D14/1 | Y | in | IOT82[A] | PCIE_HOST_RSTN/TPLL0_T_IN2/TPLL0_T_FB0 | LVCMOS33 | OFF | UP | OFF | ON | OFF | SLOW | OFF | OFF | OFF | 3.3 | MEDIUM | NONE | OFF | bus2
HP_BCK | - | Y17/7 | Y | out | IOB122[A] | - | LVCMOS33 | 8 | NONE | OFF | OFF | OFF | SLOW | OFF | OFF | OFF | 3.3 | MEDIUM | NONE | NONE | bus4
HP_WS | - | AB17/7 | Y | out | IOB108[A] | - | LVCMOS33 | 8 | NONE | OFF | OFF | OFF | SLOW | OFF | OFF | OFF | 3.3 | MEDIUM | NONE | NONE | bus4
HP_DIN | - | AA16/7 | Y | out | IOB106[A] | - | LVCMOS33 | 8 | NONE | OFF | OFF | OFF | SLOW | OFF | OFF | OFF | 3.3 | MEDIUM | NONE | NONE | bus4
PA_EN_n | - | Y14/9 | Y | out | IOB56[B] | - | LVCMOS15 | 8 | UP | OFF | OFF | OFF | SLOW | OFF | OFF | OFF | 1.5 | MEDIUM | NONE | NONE | bus4
I2S2_BCK | - | F20/2 | Y | out | IOT124[B] | - | LVCMOS33 | 8 | NONE | OFF | OFF | OFF | SLOW | OFF | OFF | OFF | 3.3 | MEDIUM | NONE | NONE | bus1
I2S2_LRCK | - | E22/2 | Y | out | IOT140[A] | - | LVCMOS33 | 8 | NONE | OFF | OFF | OFF | SLOW | OFF | OFF | OFF | 3.3 | MEDIUM | NONE | NONE | bus0
I2S2_DIN | - | D22/2 | Y | out | IOT140[B] | - | LVCMOS33 | 8 | NONE | OFF | OFF | OFF | SLOW | OFF | OFF | OFF | 3.3 | MEDIUM | NONE | NONE | bus0
tmds_d_p_0[0] | tmds_d_n_0[0] | J14/4 | Y | out | IOR26[A] | - | LVDS25 | 3.5 | NONE | OFF | OFF | NONE | NONE | OFF | OFF | OFF | 3.3 | MEDIUM | NONE | NONE | bus4
tmds_d_p_0[1] | tmds_d_n_0[1] | J15/4 | Y | out | IOR22[A] | - | LVDS25 | 3.5 | NONE | OFF | OFF | NONE | NONE | OFF | OFF | OFF | 3.3 | MEDIUM | NONE | NONE | bus4
tmds_d_p_0[2] | tmds_d_n_0[2] | K17/5 | Y | out | IOR39[A] | RPLL0_T_IN0/RPLL0_T_FB1 | LVDS25 | 3.5 | NONE | OFF | OFF | NONE | NONE | OFF | OFF | OFF | 3.3 | MEDIUM | NONE | NONE | bus4
tmds_d_n_0[0] | tmds_d_p_0[0] | H14/4 | Y | out | IOR26[B] | - | LVDS25 | 3.5 | NONE | OFF | OFF | NONE | NONE | OFF | OFF | OFF | 3.3 | MEDIUM | NONE | NONE | bus4
tmds_d_n_0[1] | tmds_d_p_0[1] | H15/4 | Y | out | IOR22[B] | - | LVDS25 | 3.5 | NONE | OFF | OFF | NONE | NONE | OFF | OFF | OFF | 3.3 | MEDIUM | NONE | NONE | bus4
tmds_d_n_0[2] | tmds_d_p_0[2] | J17/5 | Y | out | IOR39[B] | RPLL0_C_IN0/RPLL0_C_FB1 | LVDS25 | 3.5 | NONE | OFF | OFF | NONE | NONE | OFF | OFF | OFF | 3.3 | MEDIUM | NONE | NONE | bus4
tmds_clk_p_0 | tmds_clk_n_0 | G15/4 | Y | out | IOR24[A] | - | LVDS25 | 3.5 | NONE | OFF | OFF | NONE | NONE | OFF | OFF | OFF | 3.3 | MEDIUM | NONE | NONE | bus4
tmds_clk_n_0 | tmds_clk_p_0 | G16/4 | Y | out | IOR24[B] | - | LVDS25 | 3.5 | NONE | OFF | OFF | NONE | NONE | OFF | OFF | OFF | 3.3 | MEDIUM | NONE | NONE | bus4
hpd_en | - | K13/4 | Y | out | IOR36[A] | RPLL0_T_IN1/RPLL0_T_FB0 | LVCMOS33 | 12 | UP | OFF | OFF | OFF | SLOW | OFF | OFF | OFF | 3.3 | MEDIUM | NONE | NONE | bus4
led_heartbeat | - | V13/7 | Y | out | IOB124[B] | - | LVCMOS33 | 8 | NONE | OFF | OFF | OFF | SLOW | OFF | OFF | OFF | 3.3 | MEDIUM | NONE | NONE | bus4
spi_sclk | - | E14/1 | Y | out | IOT78[B] | - | LVCMOS33 | 8 | NONE | OFF | OFF | OFF | SLOW | OFF | OFF | OFF | 3.3 | MEDIUM | NONE | NONE | bus2
spi_mosi | - | E13/1 | Y | out | IOT78[A] | - | LVCMOS33 | 8 | NONE | OFF | OFF | OFF | SLOW | OFF | OFF | OFF | 3.3 | MEDIUM | NONE | NONE | bus2
spi_cs_n[0] | - | C14/1 | Y | out | IOT85[A] | - | LVCMOS33 | 8 | UP | OFF | OFF | OFF | SLOW | OFF | OFF | OFF | 3.3 | MEDIUM | NONE | NONE | -
spi_cs_n[1] | - | C13/1 | Y | out | IOT93[A] | - | LVCMOS33 | 8 | UP | OFF | OFF | OFF | SLOW | OFF | OFF | OFF | 3.3 | MEDIUM | NONE | NONE | bus2
spi_cs_n[2] | - | A13/1 | Y | out | IOT95[A] | - | LVCMOS33 | 8 | UP | OFF | OFF | OFF | SLOW | OFF | OFF | OFF | 3.3 | MEDIUM | NONE | NONE | bus2
spi_cs_n[3] | - | B15/1 | Y | out | IOT97[A] | - | LVCMOS33 | 8 | UP | OFF | OFF | OFF | SLOW | OFF | OFF | OFF | 3.3 | MEDIUM | NONE | NONE | bus2
spi_cs_n[4] | - | A15/1 | Y | out | IOT99[A] | - | LVCMOS33 | 8 | UP | OFF | OFF | OFF | SLOW | OFF | OFF | OFF | 3.3 | MEDIUM | NONE | NONE | bus2
spi_cs_n[5] | - | B20/2 | Y | out | IOT122[A] | - | LVCMOS33 | 8 | UP | OFF | OFF | OFF | SLOW | OFF | OFF | OFF | 3.3 | MEDIUM | NONE | NONE | bus1
led_sdi | - | B21/2 | Y | out | IOT135[A] | - | LVCMOS33 | 8 | NONE | OFF | OFF | OFF | SLOW | OFF | OFF | OFF | 3.3 | MEDIUM | NONE | NONE | bus0
led_clk | - | B18/1 | Y | out | IOT104[B] | GCLKC_1 | LVCMOS33 | 8 | NONE | OFF | OFF | OFF | SLOW | OFF | OFF | OFF | 3.3 | MEDIUM | NONE | NONE | bus2
led_le | - | A21/2 | Y | out | IOT135[B] | - | LVCMOS33 | 8 | NONE | OFF | OFF | OFF | SLOW | OFF | OFF | OFF | 3.3 | MEDIUM | NONE | NONE | bus0
led_oe_n[0] | - | B17/1 | Y | out | IOT104[A] | GCLKT_1 | LVCMOS33 | 8 | UP | OFF | OFF | OFF | SLOW | OFF | OFF | OFF | 3.3 | MEDIUM | NONE | NONE | bus2
led_oe_n[1] | - | C17/1 | Y | out | IOT106[B] | GCLKC_0 | LVCMOS33 | 8 | UP | OFF | OFF | OFF | SLOW | OFF | OFF | OFF | 3.3 | MEDIUM | NONE | NONE | bus2
led_oe_n[2] | - | D17/1 | Y | out | IOT106[A] | GCLKT_0 | LVCMOS33 | 8 | UP | OFF | OFF | OFF | SLOW | OFF | OFF | OFF | 3.3 | MEDIUM | NONE | NONE | bus2
led_oe_n[3] | - | A19/2 | Y | out | IOT113[B] | Q0REF_C_IN1 | LVCMOS33 | 8 | UP | OFF | OFF | OFF | SLOW | OFF | OFF | OFF | 3.3 | MEDIUM | NONE | NONE | bus1
led_oe_n[4] | - | A18/2 | Y | out | IOT113[A] | Q0REF_T_IN1 | LVCMOS33 | 8 | UP | OFF | OFF | OFF | SLOW | OFF | OFF | OFF | 3.3 | MEDIUM | NONE | NONE | bus1
uart_tx | - | D15/1 | Y | out | IOT82[B] | TPLL0_C_IN2/TPLL0_C_FB0 | LVCMOS33 | 8 | NONE | OFF | OFF | OFF | SLOW | OFF | OFF | OFF | 3.3 | MEDIUM | NONE | NONE | bus2

## All Package Pins:

Loc./Bank | Signal | Dir. | Site | CFG | IO Type | Drive | Pull Mode | PCI Clamp | Hysteresis | Open Drain | Slew Rate | Vref | Single Resistor | Diff Resistor | Bank Vccio | Pull Strength | Ctle | Threshold Offset | ADC_INPUT
E13/1 | spi_mosi | out | IOT78[A] | - | LVCMOS33 | 8 | NONE | OFF | OFF | OFF | SLOW | OFF | OFF | OFF | 3.3 | MEDIUM | NONE | NONE | bus2
E14/1 | spi_sclk | out | IOT78[B] | - | LVCMOS33 | 8 | NONE | OFF | OFF | OFF | SLOW | OFF | OFF | OFF | 3.3 | MEDIUM | NONE | NONE | bus2
F13/1 | - | in | IOT80[A] | TPLL0_T_IN1/TPLL0_T_FB1 | LVCMOS33 | OFF | UP | OFF | ON | OFF | SLOW | OFF | OFF | OFF | 3.3 | MEDIUM | NONE | OFF | bus2
F14/1 | - | in | IOT80[B] | TPLL0_C_IN1/TPLL0_C_FB1 | LVCMOS33 | OFF | UP | OFF | ON | OFF | SLOW | OFF | OFF | OFF | 3.3 | MEDIUM | NONE | OFF | bus2
D14/1 | uart_rx | in | IOT82[A] | PCIE_HOST_RSTN/TPLL0_T_IN2/TPLL0_T_FB0 | LVCMOS33 | OFF | UP | OFF | ON | OFF | SLOW | OFF | OFF | OFF | 3.3 | MEDIUM | NONE | OFF | bus2
D15/1 | uart_tx | out | IOT82[B] | TPLL0_C_IN2/TPLL0_C_FB0 | LVCMOS33 | 8 | NONE | OFF | OFF | OFF | SLOW | OFF | OFF | OFF | 3.3 | MEDIUM | NONE | NONE | bus2
C14/1 | spi_cs_n[0] | out | IOT85[A] | - | LVCMOS33 | 8 | UP | OFF | OFF | OFF | SLOW | OFF | OFF | OFF | 3.3 | MEDIUM | NONE | NONE | -
C15/1 | spi_miso[0] | in | IOT85[B] | - | LVCMOS33 | OFF | UP | OFF | ON | OFF | SLOW | OFF | OFF | OFF | 3.3 | MEDIUM | NONE | OFF | -
E16/1 | - | in | IOT87[A] | - | LVCMOS33 | OFF | UP | OFF | ON | OFF | SLOW | OFF | OFF | OFF | 3.3 | MEDIUM | NONE | OFF | bus2
D16/1 | - | in | IOT87[B] | - | LVCMOS33 | OFF | UP | OFF | ON | OFF | SLOW | OFF | OFF | OFF | 3.3 | MEDIUM | NONE | OFF | bus2
F16/1 | - | in | IOT89[A] | Q0REF_T_IN0 | LVCMOS33 | OFF | UP | OFF | ON | OFF | SLOW | OFF | OFF | OFF | 3.3 | MEDIUM | NONE | OFF | bus2
E17/1 | - | in | IOT89[B] | Q0REF_C_IN0 | LVCMOS33 | OFF | UP | OFF | ON | OFF | SLOW | OFF | OFF | OFF | 3.3 | MEDIUM | NONE | OFF | bus2
F15/1 | - | in | IOT91[A] | - | LVCMOS33 | OFF | UP | OFF | ON | OFF | SLOW | OFF | OFF | OFF | 3.3 | MEDIUM | NONE | OFF | bus2
C13/1 | spi_cs_n[1] | out | IOT93[A] | - | LVCMOS33 | 8 | UP | OFF | OFF | OFF | SLOW | OFF | OFF | OFF | 3.3 | MEDIUM | NONE | NONE | bus2
B13/1 | spi_miso[1] | in | IOT93[B] | - | LVCMOS33 | OFF | UP | OFF | ON | OFF | SLOW | OFF | OFF | OFF | 3.3 | MEDIUM | NONE | OFF | bus2
A13/1 | spi_cs_n[2] | out | IOT95[A] | - | LVCMOS33 | 8 | UP | OFF | OFF | OFF | SLOW | OFF | OFF | OFF | 3.3 | MEDIUM | NONE | NONE | bus2
A14/1 | spi_miso[2] | in | IOT95[B] | - | LVCMOS33 | OFF | UP | OFF | ON | OFF | SLOW | OFF | OFF | OFF | 3.3 | MEDIUM | NONE | OFF | bus2
B15/1 | spi_cs_n[3] | out | IOT97[A] | - | LVCMOS33 | 8 | UP | OFF | OFF | OFF | SLOW | OFF | OFF | OFF | 3.3 | MEDIUM | NONE | NONE | bus2
B16/1 | spi_miso[3] | in | IOT97[B] | - | LVCMOS33 | OFF | UP | OFF | ON | OFF | SLOW | OFF | OFF | OFF | 3.3 | MEDIUM | NONE | OFF | bus2
A15/1 | spi_cs_n[4] | out | IOT99[A] | - | LVCMOS33 | 8 | UP | OFF | OFF | OFF | SLOW | OFF | OFF | OFF | 3.3 | MEDIUM | NONE | NONE | bus2
A16/1 | spi_miso[4] | in | IOT99[B] | - | LVCMOS33 | OFF | UP | OFF | ON | OFF | SLOW | OFF | OFF | OFF | 3.3 | MEDIUM | NONE | OFF | bus2
B17/1 | led_oe_n[0] | out | IOT104[A] | GCLKT_1 | LVCMOS33 | 8 | UP | OFF | OFF | OFF | SLOW | OFF | OFF | OFF | 3.3 | MEDIUM | NONE | NONE | bus2
B18/1 | led_clk | out | IOT104[B] | GCLKC_1 | LVCMOS33 | 8 | NONE | OFF | OFF | OFF | SLOW | OFF | OFF | OFF | 3.3 | MEDIUM | NONE | NONE | bus2
D17/1 | led_oe_n[2] | out | IOT106[A] | GCLKT_0 | LVCMOS33 | 8 | UP | OFF | OFF | OFF | SLOW | OFF | OFF | OFF | 3.3 | MEDIUM | NONE | NONE | bus2
C17/1 | led_oe_n[1] | out | IOT106[B] | GCLKC_0 | LVCMOS33 | 8 | UP | OFF | OFF | OFF | SLOW | OFF | OFF | OFF | 3.3 | MEDIUM | NONE | NONE | bus2
A18/2 | led_oe_n[4] | out | IOT113[A] | Q0REF_T_IN1 | LVCMOS33 | 8 | UP | OFF | OFF | OFF | SLOW | OFF | OFF | OFF | 3.3 | MEDIUM | NONE | NONE | bus1
A19/2 | led_oe_n[3] | out | IOT113[B] | Q0REF_C_IN1 | LVCMOS33 | 8 | UP | OFF | OFF | OFF | SLOW | OFF | OFF | OFF | 3.3 | MEDIUM | NONE | NONE | bus1
C18/2 | - | in | IOT115[A] | GCLKT_3 | LVCMOS33 | OFF | UP | OFF | ON | OFF | SLOW | OFF | OFF | OFF | 3.3 | MEDIUM | NONE | OFF | bus1
C19/2 | - | in | IOT115[B] | GCLKC_3 | LVCMOS33 | OFF | UP | OFF | ON | OFF | SLOW | OFF | OFF | OFF | 3.3 | MEDIUM | NONE | OFF | bus1
F18/2 | - | in | IOT117[A] | - | LVCMOS33 | OFF | UP | OFF | ON | OFF | SLOW | OFF | OFF | OFF | 3.3 | MEDIUM | NONE | OFF | bus1
E18/2 | - | in | IOT117[B] | - | LVCMOS33 | OFF | UP | OFF | ON | OFF | SLOW | OFF | OFF | OFF | 3.3 | MEDIUM | NONE | OFF | bus1
E19/2 | - | in | IOT120[A] | GCLKT_2 | LVCMOS33 | OFF | UP | OFF | ON | OFF | SLOW | OFF | OFF | OFF | 3.3 | MEDIUM | NONE | OFF | bus1
D19/2 | - | in | IOT120[B] | GCLKC_2 | LVCMOS33 | OFF | UP | OFF | ON | OFF | SLOW | OFF | OFF | OFF | 3.3 | MEDIUM | NONE | OFF | bus1
B20/2 | spi_cs_n[5] | out | IOT122[A] | - | LVCMOS33 | 8 | UP | OFF | OFF | OFF | SLOW | OFF | OFF | OFF | 3.3 | MEDIUM | NONE | NONE | bus1
A20/2 | spi_miso[5] | in | IOT122[B] | - | LVCMOS33 | OFF | UP | OFF | ON | OFF | SLOW | OFF | OFF | OFF | 3.3 | MEDIUM | NONE | OFF | bus1
F19/2 | - | in | IOT124[A] | - | LVCMOS33 | OFF | UP | OFF | ON | OFF | SLOW | OFF | OFF | OFF | 3.3 | MEDIUM | NONE | OFF | bus1
F20/2 | I2S2_BCK | out | IOT124[B] | - | LVCMOS33 | 8 | NONE | OFF | OFF | OFF | SLOW | OFF | OFF | OFF | 3.3 | MEDIUM | NONE | NONE | bus1
D20/2 | - | in | IOT131[A] | - | LVCMOS33 | OFF | UP | OFF | ON | OFF | SLOW | OFF | OFF | OFF | 3.3 | MEDIUM | NONE | OFF | bus0
C20/2 | - | in | IOT131[B] | - | LVCMOS33 | OFF | UP | OFF | ON | OFF | SLOW | OFF | OFF | OFF | 3.3 | MEDIUM | NONE | OFF | bus0
C22/2 | - | in | IOT133[A] | - | LVCMOS33 | OFF | UP | OFF | ON | OFF | SLOW | OFF | OFF | OFF | 3.3 | MEDIUM | NONE | OFF | bus0
B22/2 | - | in | IOT133[B] | - | LVCMOS33 | OFF | UP | OFF | ON | OFF | SLOW | OFF | OFF | OFF | 3.3 | MEDIUM | NONE | OFF | bus0
B21/2 | led_sdi | out | IOT135[A] | - | LVCMOS33 | 8 | NONE | OFF | OFF | OFF | SLOW | OFF | OFF | OFF | 3.3 | MEDIUM | NONE | NONE | bus0
A21/2 | led_le | out | IOT135[B] | - | LVCMOS33 | 8 | NONE | OFF | OFF | OFF | SLOW | OFF | OFF | OFF | 3.3 | MEDIUM | NONE | NONE | bus0
E21/2 | pluck_up_i | in | IOT138[A] | - | LVCMOS33 | OFF | UP | OFF | ON | OFF | SLOW | OFF | OFF | OFF | 3.3 | MEDIUM | NONE | OFF | bus0
D21/2 | pluck_down_i | in | IOT138[B] | - | LVCMOS33 | OFF | UP | OFF | ON | OFF | SLOW | OFF | OFF | OFF | 3.3 | MEDIUM | NONE | OFF | bus0
E22/2 | I2S2_LRCK | out | IOT140[A] | - | LVCMOS33 | 8 | NONE | OFF | OFF | OFF | SLOW | OFF | OFF | OFF | 3.3 | MEDIUM | NONE | NONE | bus0
D22/2 | I2S2_DIN | out | IOT140[B] | - | LVCMOS33 | 8 | NONE | OFF | OFF | OFF | SLOW | OFF | OFF | OFF | 3.3 | MEDIUM | NONE | NONE | bus0
F21/2 | - | in | IOT142[A] | - | LVCMOS33 | OFF | UP | OFF | ON | OFF | SLOW | OFF | OFF | OFF | 3.3 | MEDIUM | NONE | OFF | bus0
G21/2 | - | in | IOT144[A] | - | LVCMOS33 | OFF | UP | OFF | ON | OFF | SLOW | OFF | OFF | OFF | 3.3 | MEDIUM | NONE | OFF | bus0
G22/2 | - | in | IOT144[B] | - | LVCMOS33 | OFF | UP | OFF | ON | OFF | SLOW | OFF | OFF | OFF | 3.3 | MEDIUM | NONE | OFF | bus0
T16/2 | - | in | IOT146[A] | TPLL1_T_IN1/TPLL1_T_FB0 | LVCMOS33 | OFF | UP | OFF | ON | OFF | SLOW | OFF | OFF | OFF | 3.3 | MEDIUM | NONE | OFF | bus0
AA9/9 | - | in | IOB1[A] | - | LVCMOS15 | OFF | UP | OFF | ON | OFF | SLOW | OFF | OFF | OFF | 1.5 | MEDIUM | NONE | OFF | bus4
AA10/9 | - | in | IOB1[B] | - | LVCMOS15 | OFF | UP | OFF | ON | OFF | SLOW | OFF | OFF | OFF | 1.5 | MEDIUM | NONE | OFF | bus4
T3/9 | - | in | IOB3[A] | BPLL0_T_IN1/BPLL0_T_FB0 | LVCMOS15 | OFF | UP | OFF | ON | OFF | SLOW | OFF | OFF | OFF | 1.5 | MEDIUM | NONE | OFF | bus4
AB10/9 | - | in | IOB3[B] | BPLL0_C_IN1/BPLL0_C_FB0 | LVCMOS15 | OFF | UP | OFF | ON | OFF | SLOW | OFF | OFF | OFF | 1.5 | MEDIUM | NONE | OFF | bus4
T1/9 | - | in | IOB5[A] | BPLL0_T_IN2/BPLL0_T_FB1 | LVCMOS15 | OFF | UP | OFF | ON | OFF | SLOW | OFF | OFF | OFF | 1.5 | MEDIUM | NONE | OFF | bus4
U1/9 | - | in | IOB5[B] | BPLL0_C_IN2/BPLL0_C_FB1 | LVCMOS15 | OFF | UP | OFF | ON | OFF | SLOW | OFF | OFF | OFF | 1.5 | MEDIUM | NONE | OFF | bus4
U2/9 | - | in | IOB7[A] | - | LVCMOS15 | OFF | UP | OFF | ON | OFF | SLOW | OFF | OFF | OFF | 1.5 | MEDIUM | NONE | OFF | bus4
V2/9 | - | in | IOB7[B] | - | LVCMOS15 | OFF | UP | OFF | ON | OFF | SLOW | OFF | OFF | OFF | 1.5 | MEDIUM | NONE | OFF | bus4
W2/9 | - | in | IOB9[A] | - | LVCMOS15 | OFF | UP | OFF | ON | OFF | SLOW | OFF | OFF | OFF | 1.5 | MEDIUM | NONE | OFF | bus4
Y2/9 | - | in | IOB9[B] | - | LVCMOS15 | OFF | UP | OFF | ON | OFF | SLOW | OFF | OFF | OFF | 1.5 | MEDIUM | NONE | OFF | bus4
R3/9 | - | in | IOB12[A] | - | LVCMOS15 | OFF | UP | OFF | ON | OFF | SLOW | OFF | OFF | OFF | 1.5 | MEDIUM | NONE | OFF | -
R2/9 | - | in | IOB12[B] | - | LVCMOS15 | OFF | UP | OFF | ON | OFF | SLOW | OFF | OFF | OFF | 1.5 | MEDIUM | NONE | OFF | -
W1/9 | - | in | IOB14[A] | - | LVCMOS15 | OFF | UP | OFF | ON | OFF | SLOW | OFF | OFF | OFF | 1.5 | MEDIUM | NONE | OFF | -
Y1/9 | - | in | IOB14[B] | - | LVCMOS15 | OFF | UP | OFF | ON | OFF | SLOW | OFF | OFF | OFF | 1.5 | MEDIUM | NONE | OFF | -
U3/9 | - | in | IOB16[A] | - | LVCMOS15 | OFF | UP | OFF | ON | OFF | SLOW | OFF | OFF | OFF | 1.5 | MEDIUM | NONE | OFF | bus4
V3/9 | - | in | IOB16[B] | - | LVCMOS15 | OFF | UP | OFF | ON | OFF | SLOW | OFF | OFF | OFF | 1.5 | MEDIUM | NONE | OFF | bus4
AB12/9 | - | in | IOB18[A] | - | LVCMOS15 | OFF | UP | OFF | ON | OFF | SLOW | OFF | OFF | OFF | 1.5 | MEDIUM | NONE | OFF | bus4
AB11/9 | - | in | IOB18[B] | - | LVCMOS15 | OFF | UP | OFF | ON | OFF | SLOW | OFF | OFF | OFF | 1.5 | MEDIUM | NONE | OFF | bus4
AA11/9 | - | in | IOB20[A] | - | LVCMOS15 | OFF | UP | OFF | ON | OFF | SLOW | OFF | OFF | OFF | 1.5 | MEDIUM | NONE | OFF | bus4
Y11/9 | - | in | IOB20[B] | - | LVCMOS15 | OFF | UP | OFF | ON | OFF | SLOW | OFF | OFF | OFF | 1.5 | MEDIUM | NONE | OFF | bus4
AA1/9 | - | in | IOB22[A] | - | LVCMOS15 | OFF | UP | OFF | ON | OFF | SLOW | OFF | OFF | OFF | 1.5 | MEDIUM | NONE | OFF | bus4
AB1/9 | - | in | IOB22[B] | - | LVCMOS15 | OFF | UP | OFF | ON | OFF | SLOW | OFF | OFF | OFF | 1.5 | MEDIUM | NONE | OFF | bus4
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
AB7/9 | - | in | IOB60[A] | - | LVCMOS15 | OFF | UP | OFF | ON | OFF | SLOW | OFF | OFF | OFF | 1.5 | MEDIUM | NONE | OFF | bus4
AB6/9 | - | in | IOB60[B] | - | LVCMOS15 | OFF | UP | OFF | ON | OFF | SLOW | OFF | OFF | OFF | 1.5 | MEDIUM | NONE | OFF | bus4
V9/9 | - | in | IOB62[A] | - | LVCMOS15 | OFF | UP | OFF | ON | OFF | SLOW | OFF | OFF | OFF | 1.5 | MEDIUM | NONE | OFF | bus4
V8/9 | - | in | IOB62[B] | - | LVCMOS15 | OFF | UP | OFF | ON | OFF | SLOW | OFF | OFF | OFF | 1.5 | MEDIUM | NONE | OFF | bus4
AA8/9 | - | in | IOB65[A] | - | LVCMOS15 | OFF | UP | OFF | ON | OFF | SLOW | OFF | OFF | OFF | 1.5 | MEDIUM | NONE | OFF | bus4
AB8/9 | - | in | IOB65[B] | - | LVCMOS15 | OFF | UP | OFF | ON | OFF | SLOW | OFF | OFF | OFF | 1.5 | MEDIUM | NONE | OFF | bus4
Y8/9 | - | in | IOB67[A] | BPLL1_T_IN0 | LVCMOS15 | OFF | UP | OFF | ON | OFF | SLOW | OFF | OFF | OFF | 1.5 | MEDIUM | NONE | OFF | bus4
Y7/9 | - | in | IOB67[B] | BPLL1_C_IN0 | LVCMOS15 | OFF | UP | OFF | ON | OFF | SLOW | OFF | OFF | OFF | 1.5 | MEDIUM | NONE | OFF | bus4
W9/9 | - | in | IOB69[A] | - | LVCMOS15 | OFF | UP | OFF | ON | OFF | SLOW | OFF | OFF | OFF | 1.5 | MEDIUM | NONE | OFF | bus4
Y9/9 | - | in | IOB69[B] | - | LVCMOS15 | OFF | UP | OFF | ON | OFF | SLOW | OFF | OFF | OFF | 1.5 | MEDIUM | NONE | OFF | bus4
U7/9 | - | in | IOB71[A] | BPLL1_T_IN1/BPLL1_T_FB1 | LVCMOS15 | OFF | UP | OFF | ON | OFF | SLOW | OFF | OFF | OFF | 1.5 | MEDIUM | NONE | OFF | bus4
V10/9 | - | in | IOB71[B] | BPLL1_C_IN1/BPLL1_C_FB1 | LVCMOS15 | OFF | UP | OFF | ON | OFF | SLOW | OFF | OFF | OFF | 1.5 | MEDIUM | NONE | OFF | bus4
U17/8 | - | in | IOB75[A] | - | LVCMOS33 | OFF | UP | OFF | ON | OFF | SLOW | OFF | OFF | OFF | 3.3 | MEDIUM | NONE | OFF | bus4
U18/8 | - | in | IOB75[B] | - | LVCMOS33 | OFF | UP | OFF | ON | OFF | SLOW | OFF | OFF | OFF | 3.3 | MEDIUM | NONE | OFF | bus4
AA18/8 | - | in | IOB77[A] | BPLL1_T_IN2/BPLL1_T_FB0 | LVCMOS33 | OFF | UP | OFF | ON | OFF | SLOW | OFF | OFF | OFF | 3.3 | MEDIUM | NONE | OFF | bus4
AB18/8 | - | in | IOB77[B] | BPLL1_C_IN2/BPLL1_C_FB0 | LVCMOS33 | OFF | UP | OFF | ON | OFF | SLOW | OFF | OFF | OFF | 3.3 | MEDIUM | NONE | OFF | bus4
V17/8 | - | in | IOB79[A] | CSI_B | LVCMOS33 | OFF | UP | OFF | ON | OFF | SLOW | OFF | OFF | OFF | 3.3 | MEDIUM | NONE | OFF | bus4
W17/8 | - | in | IOB79[B] | - | LVCMOS33 | OFF | UP | OFF | ON | OFF | SLOW | OFF | OFF | OFF | 3.3 | MEDIUM | NONE | OFF | bus4
V18/8 | - | in | IOB81[A] | GCLKT_11 | LVCMOS33 | OFF | UP | OFF | ON | OFF | SLOW | OFF | OFF | OFF | 3.3 | MEDIUM | NONE | OFF | -
V19/8 | - | in | IOB81[B] | GCLKC_11 | LVCMOS33 | OFF | UP | OFF | ON | OFF | SLOW | OFF | OFF | OFF | 3.3 | MEDIUM | NONE | OFF | -
AA19/8 | - | in | IOB85[A] | RDWR_B | LVCMOS33 | OFF | DOWN | OFF | ON | OFF | SLOW | OFF | OFF | OFF | 3.3 | MEDIUM | NONE | OFF | -
AB20/8 | - | out | IOB85[B] | CSO_B/DOUT | LVCMOS33 | 8 | UP | OFF | OFF | OFF | SLOW | OFF | OFF | OFF | 3.3 | MEDIUM | NONE | NONE | -
Y18/8 | - | in | IOB87[A] | GCLKT_10 | LVCMOS33 | OFF | UP | OFF | ON | OFF | SLOW | OFF | OFF | OFF | 3.3 | MEDIUM | NONE | OFF | bus4
Y19/8 | - | in | IOB87[B] | GCLKC_10 | LVCMOS33 | OFF | UP | OFF | ON | OFF | SLOW | OFF | OFF | OFF | 3.3 | MEDIUM | NONE | OFF | bus4
AB15/8 | - | in | IOB89[A] | - | LVCMOS33 | OFF | UP | OFF | ON | OFF | SLOW | OFF | OFF | OFF | 3.3 | MEDIUM | NONE | OFF | bus4
AA14/8 | - | in | IOB89[B] | - | LVCMOS33 | OFF | UP | OFF | ON | OFF | SLOW | OFF | OFF | OFF | 3.3 | MEDIUM | NONE | OFF | bus4
W14/8 | - | in | IOB91[A] | - | LVCMOS33 | OFF | UP | OFF | ON | OFF | SLOW | OFF | OFF | OFF | 3.3 | MEDIUM | NONE | OFF | bus4
V14/8 | - | in | IOB91[B] | - | LVCMOS33 | OFF | UP | OFF | ON | OFF | SLOW | OFF | OFF | OFF | 3.3 | MEDIUM | NONE | OFF | bus4
W19/8 | - | in | IOB93[A] | GCLKT_9 | LVCMOS33 | OFF | UP | OFF | ON | OFF | SLOW | OFF | OFF | OFF | 3.3 | MEDIUM | NONE | OFF | bus4
W20/8 | - | in | IOB93[B] | GCLKC_9 | LVCMOS33 | OFF | UP | OFF | ON | OFF | SLOW | OFF | OFF | OFF | 3.3 | MEDIUM | NONE | OFF | bus4
U20/8 | - | in | IOB95[A] | GCLKT_8 | LVCMOS33 | OFF | UP | OFF | ON | OFF | SLOW | OFF | OFF | OFF | 3.3 | MEDIUM | NONE | OFF | bus4
V20/8 | - | in | IOB95[B] | GCLKC_8 | LVCMOS33 | OFF | UP | OFF | ON | OFF | SLOW | OFF | OFF | OFF | 3.3 | MEDIUM | NONE | OFF | bus4
AB21/8 | - | in | IOB97[A] | D14 | LVCMOS33 | OFF | NONE | OFF | ON | OFF | SLOW | OFF | OFF | OFF | 3.3 | MEDIUM | NONE | OFF | bus4
AB22/8 | - | in | IOB97[B] | D15 | LVCMOS33 | OFF | NONE | OFF | ON | OFF | SLOW | OFF | OFF | OFF | 3.3 | MEDIUM | NONE | OFF | bus4
Y21/8 | - | in | IOB99[A] | - | LVCMOS33 | OFF | UP | OFF | ON | OFF | SLOW | OFF | OFF | OFF | 3.3 | MEDIUM | NONE | OFF | bus4
Y22/8 | - | in | IOB99[B] | D13 | LVCMOS33 | OFF | NONE | OFF | ON | OFF | SLOW | OFF | OFF | OFF | 3.3 | MEDIUM | NONE | OFF | bus4
AA20/7 | - | in | IOB102[A] | D11 | LVCMOS33 | OFF | NONE | OFF | ON | OFF | SLOW | OFF | OFF | OFF | 3.3 | MEDIUM | NONE | OFF | bus4
AA21/7 | - | in | IOB102[B] | D12 | LVCMOS33 | OFF | NONE | OFF | ON | OFF | SLOW | OFF | OFF | OFF | 3.3 | MEDIUM | NONE | OFF | bus4
W21/7 | - | in | IOB104[A] | D09 | LVCMOS33 | OFF | NONE | OFF | ON | OFF | SLOW | OFF | OFF | OFF | 3.3 | MEDIUM | NONE | OFF | bus4
W22/7 | - | in | IOB104[B] | D10 | LVCMOS33 | OFF | NONE | OFF | ON | OFF | SLOW | OFF | OFF | OFF | 3.3 | MEDIUM | NONE | OFF | bus4
AA16/7 | HP_DIN | out | IOB106[A] | - | LVCMOS33 | 8 | NONE | OFF | OFF | OFF | SLOW | OFF | OFF | OFF | 3.3 | MEDIUM | NONE | NONE | bus4
AA15/7 | - | in | IOB106[B] | - | LVCMOS33 | OFF | UP | OFF | ON | OFF | SLOW | OFF | OFF | OFF | 3.3 | MEDIUM | NONE | OFF | bus4
AB17/7 | HP_WS | out | IOB108[A] | - | LVCMOS33 | 8 | NONE | OFF | OFF | OFF | SLOW | OFF | OFF | OFF | 3.3 | MEDIUM | NONE | NONE | bus4
AB16/7 | - | in | IOB108[B] | - | LVCMOS33 | OFF | UP | OFF | ON | OFF | SLOW | OFF | OFF | OFF | 3.3 | MEDIUM | NONE | OFF | bus4
T19/7 | - | in | IOB111[A] | MCS_N | LVCMOS33 | OFF | UP | OFF | ON | OFF | SLOW | OFF | OFF | OFF | 3.3 | MEDIUM | NONE | OFF | bus4
T20/7 | - | in | IOB111[B] | D08 | LVCMOS33 | OFF | NONE | OFF | ON | OFF | SLOW | OFF | OFF | OFF | 3.3 | MEDIUM | NONE | OFF | bus4
P19/7 | - | in | IOB113[A] | D06 | LVCMOS33 | OFF | UP | OFF | ON | OFF | SLOW | OFF | OFF | OFF | 3.3 | MEDIUM | NONE | OFF | bus4
R19/7 | - | in | IOB113[B] | D07 | LVCMOS33 | OFF | UP | OFF | ON | OFF | SLOW | OFF | OFF | OFF | 3.3 | MEDIUM | NONE | OFF | bus4
T21/7 | - | in | IOB115[A] | D04 | LVCMOS33 | OFF | UP | OFF | ON | OFF | SLOW | OFF | OFF | OFF | 3.3 | MEDIUM | NONE | OFF | bus4
U21/7 | - | in | IOB115[B] | D05 | LVCMOS33 | OFF | UP | OFF | ON | OFF | SLOW | OFF | OFF | OFF | 3.3 | MEDIUM | NONE | OFF | bus4
U22/7 | - | in | IOB117[A] | PUDC_B | LVCMOS33 | OFF | DOWN | OFF | ON | OFF | SLOW | OFF | OFF | OFF | 3.3 | MEDIUM | NONE | OFF | bus4
V22/7 | clk | in | IOB117[B] | EMCCLK | LVCMOS33 | OFF | NONE | OFF | ON | OFF | SLOW | OFF | OFF | OFF | 3.3 | MEDIUM | NONE | OFF | bus4
P21/7 | - | in | IOB120[A] | D02/MI2 | LVCMOS33 | OFF | UP | OFF | ON | OFF | SLOW | OFF | OFF | OFF | 3.3 | MEDIUM | NONE | OFF | bus4
R21/7 | - | in | IOB120[B] | D03/MI3 | LVCMOS33 | OFF | UP | OFF | ON | OFF | SLOW | OFF | OFF | OFF | 3.3 | MEDIUM | NONE | OFF | bus4
Y17/7 | HP_BCK | out | IOB122[A] | - | LVCMOS33 | 8 | NONE | OFF | OFF | OFF | SLOW | OFF | OFF | OFF | 3.3 | MEDIUM | NONE | NONE | bus4
Y16/7 | - | in | IOB122[B] | - | LVCMOS33 | OFF | UP | OFF | ON | OFF | SLOW | OFF | OFF | OFF | 3.3 | MEDIUM | NONE | OFF | bus4
P20/7 | - | in | IOB124[A] | - | LVCMOS33 | OFF | UP | OFF | ON | OFF | SLOW | OFF | OFF | OFF | 3.3 | MEDIUM | NONE | OFF | bus4
V13/7 | led_heartbeat | out | IOB124[B] | - | LVCMOS33 | 8 | NONE | OFF | OFF | OFF | SLOW | OFF | OFF | OFF | 3.3 | MEDIUM | NONE | NONE | bus4
W16/7 | - | in | IOB126[A] | - | LVCMOS33 | OFF | UP | OFF | ON | OFF | SLOW | OFF | OFF | OFF | 3.3 | MEDIUM | NONE | OFF | bus4
W15/7 | - | in | IOB126[B] | - | LVCMOS33 | OFF | UP | OFF | ON | OFF | SLOW | OFF | OFF | OFF | 3.3 | MEDIUM | NONE | OFF | bus4
P22/6 | - | in | IOB128[A] | D00/MOSI/MI0 | LVCMOS33 | OFF | UP | OFF | ON | OFF | SLOW | OFF | OFF | OFF | 3.3 | MEDIUM | NONE | OFF | bus4
R22/6 | - | in | IOB128[B] | D01/DIN/MISO/MI1 | LVCMOS33 | OFF | UP | OFF | ON | OFF | SLOW | OFF | OFF | OFF | 3.3 | MEDIUM | NONE | OFF | bus4
V15/6 | - | in | IOB130[A] | - | LVCMOS33 | OFF | UP | OFF | ON | OFF | SLOW | OFF | OFF | OFF | 3.3 | MEDIUM | NONE | OFF | bus4
U15/6 | - | in | IOB130[B] | - | LVCMOS33 | OFF | UP | OFF | ON | OFF | SLOW | OFF | OFF | OFF | 3.3 | MEDIUM | NONE | OFF | bus4
T15/6 | - | in | IOB132[A] | - | LVCMOS33 | OFF | UP | OFF | ON | OFF | SLOW | OFF | OFF | OFF | 3.3 | MEDIUM | NONE | OFF | bus4
T14/6 | - | in | IOB132[B] | - | LVCMOS33 | OFF | UP | OFF | ON | OFF | SLOW | OFF | OFF | OFF | 3.3 | MEDIUM | NONE | OFF | bus4
U16/6 | - | in | IOB134[A] | - | LVCMOS33 | OFF | UP | OFF | ON | OFF | SLOW | OFF | OFF | OFF | 3.3 | MEDIUM | NONE | OFF | bus4
N15/6 | - | in | IOB134[B] | - | LVCMOS33 | OFF | UP | OFF | ON | OFF | SLOW | OFF | OFF | OFF | 3.3 | MEDIUM | NONE | OFF | bus4
P16/6 | - | in | IOB136[A] | - | LVCMOS33 | OFF | UP | OFF | ON | OFF | SLOW | OFF | OFF | OFF | 3.3 | MEDIUM | NONE | OFF | bus4
R17/6 | - | in | IOB136[B] | - | LVCMOS33 | OFF | UP | OFF | ON | OFF | SLOW | OFF | OFF | OFF | 3.3 | MEDIUM | NONE | OFF | bus4
N13/6 | - | in | IOB138[A] | - | LVCMOS33 | OFF | UP | OFF | ON | OFF | SLOW | OFF | OFF | OFF | 3.3 | MEDIUM | NONE | OFF | bus4
N14/6 | - | in | IOB138[B] | - | LVCMOS33 | OFF | UP | OFF | ON | OFF | SLOW | OFF | OFF | OFF | 3.3 | MEDIUM | NONE | OFF | bus4
N17/6 | - | in | IOB140[A] | - | LVCMOS33 | OFF | UP | OFF | ON | OFF | SLOW | OFF | OFF | OFF | 3.3 | MEDIUM | NONE | OFF | bus4
P17/6 | - | in | IOB140[B] | - | LVCMOS33 | OFF | UP | OFF | ON | OFF | SLOW | OFF | OFF | OFF | 3.3 | MEDIUM | NONE | OFF | bus4
P15/6 | - | in | IOB142[A] | - | LVCMOS33 | OFF | UP | OFF | ON | OFF | SLOW | OFF | OFF | OFF | 3.3 | MEDIUM | NONE | OFF | bus4
R16/6 | - | in | IOB142[B] | - | LVCMOS33 | OFF | UP | OFF | ON | OFF | SLOW | OFF | OFF | OFF | 3.3 | MEDIUM | NONE | OFF | bus4
R18/6 | - | in | IOB144[A] | - | LVCMOS33 | OFF | UP | OFF | ON | OFF | SLOW | OFF | OFF | OFF | 3.3 | MEDIUM | NONE | OFF | -
T18/6 | - | in | IOB144[B] | - | LVCMOS33 | OFF | UP | OFF | ON | OFF | SLOW | OFF | OFF | OFF | 3.3 | MEDIUM | NONE | OFF | -
P14/6 | - | in | IOB146[A] | - | LVCMOS33 | OFF | UP | OFF | ON | OFF | SLOW | OFF | OFF | OFF | 3.3 | MEDIUM | NONE | OFF | -
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
M3/10 | - | in | IOL54[A] | - | LVCMOS33 | OFF | UP | OFF | ON | OFF | SLOW | OFF | OFF | OFF | 3.3 | MEDIUM | NONE | OFF | bus2
M2/10 | - | in | IOL54[B] | - | LVCMOS33 | OFF | UP | OFF | ON | OFF | SLOW | OFF | OFF | OFF | 3.3 | MEDIUM | NONE | OFF | bus2
K6/10 | - | in | IOL57[A] | - | LVCMOS33 | OFF | UP | OFF | ON | OFF | SLOW | OFF | OFF | OFF | 3.3 | MEDIUM | NONE | OFF | bus2
J6/10 | - | in | IOL57[B] | - | LVCMOS33 | OFF | UP | OFF | ON | OFF | SLOW | OFF | OFF | OFF | 3.3 | MEDIUM | NONE | OFF | bus2
L5/10 | - | in | IOL59[A] | - | LVCMOS33 | OFF | UP | OFF | ON | OFF | SLOW | OFF | OFF | OFF | 3.3 | MEDIUM | NONE | OFF | bus2
L4/10 | - | in | IOL59[B] | - | LVCMOS33 | OFF | UP | OFF | ON | OFF | SLOW | OFF | OFF | OFF | 3.3 | MEDIUM | NONE | OFF | bus2
N4/10 | - | in | IOL61[A] | - | LVCMOS33 | OFF | UP | OFF | ON | OFF | SLOW | OFF | OFF | OFF | 3.3 | MEDIUM | NONE | OFF | bus2
N3/10 | - | in | IOL61[B] | - | LVCMOS33 | OFF | UP | OFF | ON | OFF | SLOW | OFF | OFF | OFF | 3.3 | MEDIUM | NONE | OFF | bus2
R1/10 | - | in | IOL63[A] | LPLL1_T_IN0 | LVCMOS33 | OFF | UP | OFF | ON | OFF | SLOW | OFF | OFF | OFF | 3.3 | MEDIUM | NONE | OFF | -
P1/10 | - | in | IOL63[B] | LPLL1_C_IN0 | LVCMOS33 | OFF | UP | OFF | ON | OFF | SLOW | OFF | OFF | OFF | 3.3 | MEDIUM | NONE | OFF | -
L6/10 | - | in | IOL65[A] | - | LVCMOS33 | OFF | UP | OFF | ON | OFF | SLOW | OFF | OFF | OFF | 3.3 | MEDIUM | NONE | OFF | bus2
P5/10 | - | in | IOL66[A] | LPLL1_T_IN1/LPLL1_T_FB0 | LVCMOS33 | OFF | UP | OFF | ON | OFF | SLOW | OFF | OFF | OFF | 3.3 | MEDIUM | NONE | OFF | bus2
P4/10 | - | in | IOL66[B] | LPLL1_C_IN1/LPLL1_C_FB0 | LVCMOS33 | OFF | UP | OFF | ON | OFF | SLOW | OFF | OFF | OFF | 3.3 | MEDIUM | NONE | OFF | bus2
P2/10 | - | in | IOL68[A] | LPLL1_T_IN2/LPLL1_T_FB0 | LVCMOS33 | OFF | UP | OFF | ON | OFF | SLOW | OFF | OFF | OFF | 3.3 | MEDIUM | NONE | OFF | bus2
N2/10 | - | in | IOL68[B] | LPLL1_C_IN2/LPLL1_C_FB0 | LVCMOS33 | OFF | UP | OFF | ON | OFF | SLOW | OFF | OFF | OFF | 3.3 | MEDIUM | NONE | OFF | bus2
M6/10 | - | in | IOL70[A] | BPLL0_T_IN0 | LVCMOS33 | OFF | UP | OFF | ON | OFF | SLOW | OFF | OFF | OFF | 3.3 | MEDIUM | NONE | OFF | bus2
M5/10 | - | in | IOL70[B] | BPLL0_C_IN0 | LVCMOS33 | OFF | UP | OFF | ON | OFF | SLOW | OFF | OFF | OFF | 3.3 | MEDIUM | NONE | OFF | bus2
P6/10 | - | in | IOL72[A] | - | LVCMOS33 | OFF | UP | OFF | ON | OFF | SLOW | OFF | OFF | OFF | 3.3 | MEDIUM | NONE | OFF | -
N5/10 | - | in | IOL72[B] | - | LVCMOS33 | OFF | UP | OFF | ON | OFF | SLOW | OFF | OFF | OFF | 3.3 | MEDIUM | NONE | OFF | -
V12/12 | - | in | IOR1[A] | TCK | LVCMOS33 | OFF | UP | OFF | ON | OFF | SLOW | OFF | OFF | OFF | 3.3 | MEDIUM | NONE | OFF | -
R13/12 | - | in | IOR1[B] | TDI | LVCMOS33 | OFF | UP | OFF | ON | OFF | SLOW | OFF | OFF | OFF | 3.3 | MEDIUM | NONE | OFF | -
T13/12 | - | in | IOR3[A] | TMS | LVCMOS33 | OFF | UP | OFF | ON | OFF | SLOW | OFF | OFF | OFF | 3.3 | MEDIUM | NONE | OFF | -
U13/12 | - | out | IOR3[B] | TDO | LVCMOS33 | 8 | UP | OFF | OFF | OFF | SLOW | OFF | OFF | OFF | 3.3 | MEDIUM | NONE | NONE | -
L12/3 | - | in | IOR5[A] | CCLK | LVCMOS33 | OFF | UP | OFF | ON | OFF | SLOW | OFF | OFF | OFF | 3.3 | MEDIUM | NONE | OFF | -
U12/3 | - | in | IOR5[B] | READY | LVCMOS33 | OFF | UP | OFF | ON | OFF | SLOW | OFF | OFF | OFF | 3.3 | MEDIUM | NONE | OFF | -
U10/3 | - | in | IOR7[A] | MODE1 | LVCMOS33 | OFF | UP | OFF | ON | OFF | SLOW | OFF | OFF | OFF | 3.3 | MEDIUM | NONE | OFF | -
U11/3 | - | in | IOR7[B] | MODE0 | LVCMOS33 | OFF | UP | OFF | ON | OFF | SLOW | OFF | OFF | OFF | 3.3 | MEDIUM | NONE | OFF | -
G11/3 | - | in | IOR9[A] | DONE | LVCMOS33 | OFF | UP | OFF | ON | OFF | SLOW | OFF | OFF | OFF | 3.3 | MEDIUM | NONE | OFF | -
N12/3 | - | in | IOR9[B] | RECONFIG_N | LVCMOS33 | OFF | UP | OFF | ON | OFF | SLOW | OFF | OFF | OFF | 3.3 | MEDIUM | NONE | OFF | -
U8/3 | - | in | IOR11[A] | TPLL1_T_IN0/TPLL1_T_FB1 | LVCMOS33 | OFF | UP | OFF | ON | OFF | SLOW | OFF | OFF | OFF | 3.3 | MEDIUM | NONE | OFF | bus3
U9/3 | - | in | IOR11[B] | MODE2/TPLL1_C_IN0/TPLL1_C_FB1 | LVCMOS33 | OFF | UP | OFF | ON | OFF | SLOW | OFF | OFF | OFF | 3.3 | MEDIUM | NONE | OFF | bus3
H13/4 | - | in | IOR20[A] | - | LVCMOS33 | OFF | UP | OFF | ON | OFF | SLOW | OFF | OFF | OFF | 3.3 | MEDIUM | NONE | OFF | bus4
G13/4 | - | in | IOR20[B] | - | LVCMOS33 | OFF | UP | OFF | ON | OFF | SLOW | OFF | OFF | OFF | 3.3 | MEDIUM | NONE | OFF | bus4
J15/4 | tmds_d_p_0[1] | out | IOR22[A] | - | LVDS25 | 3.5 | NONE | OFF | OFF | NONE | NONE | OFF | OFF | OFF | 3.3 | MEDIUM | NONE | NONE | bus4
H15/4 | tmds_d_n_0[1] | out | IOR22[B] | - | LVDS25 | 3.5 | NONE | OFF | OFF | NONE | NONE | OFF | OFF | OFF | 3.3 | MEDIUM | NONE | NONE | bus4
G15/4 | tmds_clk_p_0 | out | IOR24[A] | - | LVDS25 | 3.5 | NONE | OFF | OFF | NONE | NONE | OFF | OFF | OFF | 3.3 | MEDIUM | NONE | NONE | bus4
G16/4 | tmds_clk_n_0 | out | IOR24[B] | - | LVDS25 | 3.5 | NONE | OFF | OFF | NONE | NONE | OFF | OFF | OFF | 3.3 | MEDIUM | NONE | NONE | bus4
J14/4 | tmds_d_p_0[0] | out | IOR26[A] | - | LVDS25 | 3.5 | NONE | OFF | OFF | NONE | NONE | OFF | OFF | OFF | 3.3 | MEDIUM | NONE | NONE | bus4
H14/4 | tmds_d_n_0[0] | out | IOR26[B] | - | LVDS25 | 3.5 | NONE | OFF | OFF | NONE | NONE | OFF | OFF | OFF | 3.3 | MEDIUM | NONE | NONE | bus4
G17/4 | - | in | IOR30[A] | - | LVCMOS33 | OFF | UP | OFF | ON | OFF | SLOW | OFF | OFF | OFF | 3.3 | MEDIUM | NONE | OFF | bus4
G18/4 | - | in | IOR30[B] | - | LVCMOS33 | OFF | UP | OFF | ON | OFF | SLOW | OFF | OFF | OFF | 3.3 | MEDIUM | NONE | OFF | bus4
H17/4 | - | in | IOR32[A] | - | LVCMOS33 | OFF | UP | OFF | ON | OFF | SLOW | OFF | OFF | OFF | 3.3 | MEDIUM | NONE | OFF | -
H18/4 | - | in | IOR32[B] | - | LVCMOS33 | OFF | UP | OFF | ON | OFF | SLOW | OFF | OFF | OFF | 3.3 | MEDIUM | NONE | OFF | -
L16/4 | - | in | IOR34[A] | - | LVCMOS33 | OFF | UP | OFF | ON | OFF | SLOW | OFF | OFF | OFF | 3.3 | MEDIUM | NONE | OFF | -
K16/4 | - | in | IOR34[B] | - | LVCMOS33 | OFF | UP | OFF | ON | OFF | SLOW | OFF | OFF | OFF | 3.3 | MEDIUM | NONE | OFF | -
K13/4 | hpd_en | out | IOR36[A] | RPLL0_T_IN1/RPLL0_T_FB0 | LVCMOS33 | 12 | UP | OFF | OFF | OFF | SLOW | OFF | OFF | OFF | 3.3 | MEDIUM | NONE | NONE | bus4
K14/4 | - | in | IOR36[B] | RPLL0_C_IN1/RPLL0_C_FB0 | LVCMOS33 | OFF | UP | OFF | ON | OFF | SLOW | OFF | OFF | OFF | 3.3 | MEDIUM | NONE | OFF | bus4
K17/5 | tmds_d_p_0[2] | out | IOR39[A] | RPLL0_T_IN0/RPLL0_T_FB1 | LVDS25 | 3.5 | NONE | OFF | OFF | NONE | NONE | OFF | OFF | OFF | 3.3 | MEDIUM | NONE | NONE | bus4
J17/5 | tmds_d_n_0[2] | out | IOR39[B] | RPLL0_C_IN0/RPLL0_C_FB1 | LVDS25 | 3.5 | NONE | OFF | OFF | NONE | NONE | OFF | OFF | OFF | 3.3 | MEDIUM | NONE | NONE | bus4
J19/5 | - | in | IOR41[A] | GCLKT_7 | LVCMOS33 | OFF | UP | OFF | ON | OFF | SLOW | OFF | OFF | OFF | 3.3 | MEDIUM | NONE | OFF | bus4
H19/5 | - | in | IOR41[B] | GCLKC_7 | LVCMOS33 | OFF | UP | OFF | ON | OFF | SLOW | OFF | OFF | OFF | 3.3 | MEDIUM | NONE | OFF | bus4
H20/5 | - | in | IOR43[A] | - | LVCMOS33 | OFF | UP | OFF | ON | OFF | SLOW | OFF | OFF | OFF | 3.3 | MEDIUM | NONE | OFF | -
G20/5 | - | in | IOR43[B] | - | LVCMOS33 | OFF | UP | OFF | ON | OFF | SLOW | OFF | OFF | OFF | 3.3 | MEDIUM | NONE | OFF | -
J22/5 | - | in | IOR45[A] | - | LVCMOS33 | OFF | UP | OFF | ON | OFF | SLOW | OFF | OFF | OFF | 3.3 | MEDIUM | NONE | OFF | bus4
H22/5 | - | in | IOR45[B] | - | LVCMOS33 | OFF | UP | OFF | ON | OFF | SLOW | OFF | OFF | OFF | 3.3 | MEDIUM | NONE | OFF | bus4
J16/5 | - | in | IOR47[A] | - | LVCMOS33 | OFF | UP | OFF | ON | OFF | SLOW | OFF | OFF | OFF | 3.3 | MEDIUM | NONE | OFF | bus4
L14/5 | - | in | IOR48[A] | - | LVCMOS33 | OFF | UP | OFF | ON | OFF | SLOW | OFF | OFF | OFF | 3.3 | MEDIUM | NONE | OFF | bus4
L15/5 | - | in | IOR48[B] | - | LVCMOS33 | OFF | UP | OFF | ON | OFF | SLOW | OFF | OFF | OFF | 3.3 | MEDIUM | NONE | OFF | bus4
M13/5 | - | in | IOR50[A] | - | LVCMOS33 | OFF | UP | OFF | ON | OFF | SLOW | OFF | OFF | OFF | 3.3 | MEDIUM | NONE | OFF | bus4
L13/5 | - | in | IOR50[B] | - | LVCMOS33 | OFF | UP | OFF | ON | OFF | SLOW | OFF | OFF | OFF | 3.3 | MEDIUM | NONE | OFF | bus4
M15/5 | - | in | IOR52[A] | - | LVCMOS33 | OFF | UP | OFF | ON | OFF | SLOW | OFF | OFF | OFF | 3.3 | MEDIUM | NONE | OFF | bus4
M16/5 | - | in | IOR52[B] | - | LVCMOS33 | OFF | UP | OFF | ON | OFF | SLOW | OFF | OFF | OFF | 3.3 | MEDIUM | NONE | OFF | bus4
J20/5 | - | in | IOR54[A] | GCLKT_5 | LVCMOS33 | OFF | UP | OFF | ON | OFF | SLOW | OFF | OFF | OFF | 3.3 | MEDIUM | NONE | OFF | bus4
J21/5 | - | in | IOR54[B] | GCLKC_5 | LVCMOS33 | OFF | UP | OFF | ON | OFF | SLOW | OFF | OFF | OFF | 3.3 | MEDIUM | NONE | OFF | bus4
M17/5 | - | in | IOR56[A] | - | LVCMOS33 | OFF | UP | OFF | ON | OFF | SLOW | OFF | OFF | OFF | 3.3 | MEDIUM | NONE | OFF | bus4
K18/5 | - | in | IOR57[A] | GCLKT_6 | LVCMOS33 | OFF | UP | OFF | ON | OFF | SLOW | OFF | OFF | OFF | 3.3 | MEDIUM | NONE | OFF | bus4
K19/5 | - | in | IOR57[B] | GCLKC_6 | LVCMOS33 | OFF | UP | OFF | ON | OFF | SLOW | OFF | OFF | OFF | 3.3 | MEDIUM | NONE | OFF | bus4
K21/5 | - | in | IOR59[A] | - | LVCMOS33 | OFF | UP | OFF | ON | OFF | SLOW | OFF | OFF | OFF | 3.3 | MEDIUM | NONE | OFF | bus4
K22/5 | - | in | IOR59[B] | - | LVCMOS33 | OFF | UP | OFF | ON | OFF | SLOW | OFF | OFF | OFF | 3.3 | MEDIUM | NONE | OFF | bus4
L19/5 | - | in | IOR61[A] | SDA/GCLKT_4/RPLL1_T_IN2/RPLL1_T_FB0 | LVCMOS33 | OFF | UP | OFF | ON | OFF | SLOW | OFF | OFF | OFF | 3.3 | MEDIUM | NONE | OFF | bus4
L20/5 | - | in | IOR61[B] | SCL/GCLKC_4/RPLL1_C_IN2/RPLL1_C_FB0 | LVCMOS33 | OFF | UP | OFF | ON | OFF | SLOW | OFF | OFF | OFF | 3.3 | MEDIUM | NONE | OFF | bus4
N22/5 | - | in | IOR63[A] | SI/SSI0 | LVCMOS33 | OFF | UP | OFF | ON | OFF | SLOW | OFF | OFF | OFF | 3.3 | MEDIUM | NONE | OFF | -
M22/5 | - | in | IOR63[B] | SSPI_CS_N | LVCMOS33 | OFF | UP | OFF | ON | OFF | SLOW | OFF | OFF | OFF | 3.3 | MEDIUM | NONE | OFF | -
M18/5 | - | in | IOR66[A] | SO/SSI1/RPLL1_T_IN1/RPLL1_T_FB1 | LVCMOS33 | OFF | UP | OFF | ON | OFF | SLOW | OFF | OFF | OFF | 3.3 | MEDIUM | NONE | OFF | bus4
L18/5 | - | in | IOR66[B] | SSPI_CLK/RPLL1_C_IN1/RPLL1_C_FB1 | LVCMOS33 | OFF | UP | OFF | ON | OFF | SLOW | OFF | OFF | OFF | 3.3 | MEDIUM | NONE | OFF | bus4
M21/5 | - | in | IOR68[A] | - | LVCMOS33 | OFF | UP | OFF | ON | OFF | SLOW | OFF | OFF | OFF | 3.3 | MEDIUM | NONE | OFF | bus4
L21/5 | - | in | IOR68[B] | - | LVCMOS33 | OFF | UP | OFF | ON | OFF | SLOW | OFF | OFF | OFF | 3.3 | MEDIUM | NONE | OFF | bus4
N20/5 | - | in | IOR70[A] | SSPI_WPN/SSI2 | LVCMOS33 | OFF | UP | OFF | ON | OFF | SLOW | OFF | OFF | OFF | 3.3 | MEDIUM | NONE | OFF | -
M20/5 | - | in | IOR70[B] | CLKHOLD_N/SSI3 | LVCMOS33 | OFF | UP | OFF | ON | OFF | SLOW | OFF | OFF | OFF | 3.3 | MEDIUM | NONE | OFF | -
N18/5 | - | in | IOR72[A] | RPLL1_T_IN0 | LVCMOS33 | OFF | UP | OFF | ON | OFF | SLOW | OFF | OFF | OFF | 3.3 | MEDIUM | NONE | OFF | -
N19/5 | - | in | IOR72[B] | RPLL1_C_IN0 | LVCMOS33 | OFF | UP | OFF | ON | OFF | SLOW | OFF | OFF | OFF | 3.3 | MEDIUM | NONE | OFF | -
N9/ADC | - | in | ADCTN | - | - | - | - | - | - | - | - | - | - | - | - | - | - | - | -
N10/ADC | - | in | ADCTP | - | - | - | - | - | - | - | - | - | - | - | - | - | - | - | -
M9/ADC | - | in | ADCVN | - | - | - | - | - | - | - | - | - | - | - | - | - | - | - | -
L10/ADC | - | in | ADCVP | - | - | - | - | - | - | - | - | - | - | - | - | - | - | - | -
F8/Q0 | - | inout | Q0_ATEST_O | - | - | - | - | - | - | - | - | - | - | - | - | - | - | - | -
A8/Q0 | - | in | Q0_LN0_RXM_I | - | - | - | - | - | - | - | - | - | - | - | - | - | - | - | -
B8/Q0 | - | in | Q0_LN0_RXP_I | - | - | - | - | - | - | - | - | - | - | - | - | - | - | - | -
A4/Q0 | - | out | Q0_LN0_TXM_O | - | - | - | - | - | - | - | - | - | - | - | - | - | - | - | -
B4/Q0 | - | out | Q0_LN0_TXP_O | - | - | - | - | - | - | - | - | - | - | - | - | - | - | - | -
C11/Q0 | - | in | Q0_LN1_RXM_I | - | - | - | - | - | - | - | - | - | - | - | - | - | - | - | -
D11/Q0 | - | in | Q0_LN1_RXP_I | - | - | - | - | - | - | - | - | - | - | - | - | - | - | - | -
C5/Q0 | - | out | Q0_LN1_TXM_O | - | - | - | - | - | - | - | - | - | - | - | - | - | - | - | -
D5/Q0 | - | out | Q0_LN1_TXP_O | - | - | - | - | - | - | - | - | - | - | - | - | - | - | - | -
A10/Q0 | - | in | Q0_LN2_RXM_I | - | - | - | - | - | - | - | - | - | - | - | - | - | - | - | -
B10/Q0 | - | in | Q0_LN2_RXP_I | - | - | - | - | - | - | - | - | - | - | - | - | - | - | - | -
A6/Q0 | - | out | Q0_LN2_TXM_O | - | - | - | - | - | - | - | - | - | - | - | - | - | - | - | -
B6/Q0 | - | out | Q0_LN2_TXP_O | - | - | - | - | - | - | - | - | - | - | - | - | - | - | - | -
C9/Q0 | - | in | Q0_LN3_RXM_I | - | - | - | - | - | - | - | - | - | - | - | - | - | - | - | -
D9/Q0 | - | in | Q0_LN3_RXP_I | - | - | - | - | - | - | - | - | - | - | - | - | - | - | - | -
C7/Q0 | - | out | Q0_LN3_TXM_O | - | - | - | - | - | - | - | - | - | - | - | - | - | - | - | -
D7/Q0 | - | out | Q0_LN3_TXP_O | - | - | - | - | - | - | - | - | - | - | - | - | - | - | - | -
E6/Q0 | - | in | Q0_REFCLKM_0 | - | - | - | - | - | - | - | - | - | - | - | - | - | - | - | -
E10/Q0 | - | in | Q0_REFCLKM_1 | - | - | - | - | - | - | - | - | - | - | - | - | - | - | - | -
F6/Q0 | - | in | Q0_REFCLKP_0 | - | - | - | - | - | - | - | - | - | - | - | - | - | - | - | -
F10/Q0 | - | in | Q0_REFCLKP_1 | - | - | - | - | - | - | - | - | - | - | - | - | - | - | - | -
