hokuu1102/Gowin2026-PolySynth/evidence/h5/build-c1-default-margin-fail/main-timing.html

# Timing Messages

Report Title | Timing Analysis Report
Design File | C:\Users\cyx\Documents\ChatGPT\FPGA\Gowin2026-PolySynth-t31b-main\impl\gwsynthesis\Gowin2026.vg
Physical Constraints File | C:\Users\cyx\Documents\ChatGPT\FPGA\Gowin2026-PolySynth-t31b-main\constr\top.cst
Timing Constraint File | C:\Users\cyx\Documents\ChatGPT\FPGA\Gowin2026-PolySynth-t31b-main\constr\top.sdc
Tool Version | V1.9.12.03 (64-bit)
Part Number | GW5AT-LV60PG484AC1/I0
Device | GW5AT-60
Device Version | B
Created Time | Thu Oct 1 19:00:10 2026
Legal Announcement | Copyright (C)2014-2026 Gowin Semiconductor Corporation. All rights reserved.

# Timing Summaries

## STA Tool Run Summary:

Setup Delay Model | Slow 0.93V 0C C1/I0
Hold Delay Model | Fast 0.975V 85C C1/I0
Numbers of Paths Analyzed | 49773
Numbers of Endpoints Analyzed | 50658
Numbers of Falling Endpoints | 26
Numbers of Setup Violated Endpoints | 0
Numbers of Hold Violated Endpoints | 0

## Clock Summary:

NO. | Clock Name | Type | Period | Frequency(MHz) | Rise | Fall | Source | Master | Objects
1 | clk_sys | Base | 20.000 | 50.000 | 0.000 | 10.000 | | | clk
2 | serial_clk | Generated | 8.000 | 125.000 | 0.000 | 4.000 | clk | clk_sys | u_hdmi/u_clk/u_pll/CLKOUT0
3 | pixel_clk | Generated | 40.000 | 25.000 | 0.000 | 20.000 | clk | clk_sys | u_hdmi/u_clk/u_pll/CLKOUT1

## Max Frequency Summary:

NO. | Clock Name | Constraint | Actual Fmax | Logic Level | Entity
1 | clk_sys | 50.000(MHz) | 50.490(MHz) | 20 | TOP
2 | pixel_clk | 25.000(MHz) | 118.906(MHz) | 10 | TOP

#### No timing paths to get frequency of serial_clk!

## Total Negative Slack Summary:

Clock Name | Analysis Type | Endpoints TNS | Number of Endpoints
clk_sys | Setup | 0.000 | 0
clk_sys | Hold | 0.000 | 0
serial_clk | Setup | 0.000 | 0
serial_clk | Hold | 0.000 | 0
pixel_clk | Setup | 0.000 | 0
pixel_clk | Hold | 0.000 | 0

# Timing Details

## Path Slacks Table:

### Setup Paths Table

#### Report Command:report_timing -setup -max_paths 25 -max_common_paths 1

Path Number | Path Slack | From Node | To Node | From Clock | To Clock | Relation | Clock Skew | Data Delay
1 | 0.194 | g_sound.u_evt_merge/cnt_q_0_s0/Q | g_sound.u_evt_merge/mem_mem_RAMREG_1_G[48]_s0/CE | clk_sys:[R] | clk_sys:[R] | 20.000 | -0.008 | 19.534
2 | 0.194 | g_sound.u_evt_merge/cnt_q_0_s0/Q | g_sound.u_evt_merge/mem_mem_RAMREG_1_G[44]_s0/CE | clk_sys:[R] | clk_sys:[R] | 20.000 | -0.008 | 19.534
3 | 0.194 | g_sound.u_evt_merge/cnt_q_0_s0/Q | g_sound.u_evt_merge/mem_mem_RAMREG_1_G[42]_s0/CE | clk_sys:[R] | clk_sys:[R] | 20.000 | -0.008 | 19.534
4 | 0.194 | g_sound.u_evt_merge/cnt_q_0_s0/Q | g_sound.u_evt_merge/mem_mem_RAMREG_1_G[41]_s0/CE | clk_sys:[R] | clk_sys:[R] | 20.000 | -0.008 | 19.534
5 | 0.194 | g_sound.u_evt_merge/cnt_q_0_s0/Q | g_sound.u_evt_merge/mem_mem_RAMREG_1_G[39]_s0/CE | clk_sys:[R] | clk_sys:[R] | 20.000 | -0.008 | 19.534
6 | 0.222 | g_sound.u_evt_merge/cnt_q_0_s0/Q | g_sound.u_evt_merge/mem_mem_RAMREG_4_G[28]_s0/CE | clk_sys:[R] | clk_sys:[R] | 20.000 | -0.008 | 19.506
7 | 0.229 | g_sound.u_evt_merge/cnt_q_0_s0/Q | g_sound.u_evt_merge/mem_mem_RAMREG_6_G[21]_s0/CE | clk_sys:[R] | clk_sys:[R] | 20.000 | -0.017 | 19.508
8 | 0.324 | g_sound.u_evt_merge/cnt_q_0_s0/Q | g_sound.u_evt_merge/mem_mem_RAMREG_1_G[20]_s0/CE | clk_sys:[R] | clk_sys:[R] | 20.000 | -0.017 | 19.413
9 | 0.378 | g_sound.u_evt_merge/cnt_q_0_s0/Q | g_sound.u_evt_merge/mem_mem_RAMREG_6_G[28]_s0/CE | clk_sys:[R] | clk_sys:[R] | 20.000 | 0.000 | 19.342
10 | 0.378 | g_sound.u_evt_merge/cnt_q_0_s0/Q | g_sound.u_evt_merge/mem_mem_RAMREG_6_G[25]_s0/CE | clk_sys:[R] | clk_sys:[R] | 20.000 | 0.000 | 19.342
11 | 0.378 | g_sound.u_evt_merge/cnt_q_0_s0/Q | g_sound.u_evt_merge/mem_mem_RAMREG_1_G[29]_s0/CE | clk_sys:[R] | clk_sys:[R] | 20.000 | -0.017 | 19.358
12 | 0.393 | g_sound.u_evt_merge/cnt_q_0_s0/Q | g_sound.u_evt_merge/mem_mem_RAMREG_4_G[40]_s0/CE | clk_sys:[R] | clk_sys:[R] | 20.000 | -0.008 | 19.335
13 | 0.520 | g_sound.u_evt_merge/cnt_q_0_s0/Q | g_sound.u_evt_merge/mem_mem_RAMREG_1_G[10]_s0/CE | clk_sys:[R] | clk_sys:[R] | 20.000 | -0.008 | 19.208
14 | 0.520 | g_sound.u_evt_merge/cnt_q_0_s0/Q | g_sound.u_evt_merge/mem_mem_RAMREG_1_G[7]_s0/CE | clk_sys:[R] | clk_sys:[R] | 20.000 | -0.008 | 19.208
15 | 0.520 | g_sound.u_evt_merge/cnt_q_0_s0/Q | g_sound.u_evt_merge/mem_mem_RAMREG_1_G[5]_s0/CE | clk_sys:[R] | clk_sys:[R] | 20.000 | -0.008 | 19.208
16 | 0.537 | g_sound.u_adc_farm/u_scan0/sample_channel_0_s0/Q | g_sound.u_calib1/n840_s/A[1] | clk_sys:[R] | clk_sys:[R] | 20.000 | 0.008 | 16.075
17 | 0.566 | g_sound.u_evt_merge/cnt_q_0_s0/Q | g_sound.u_evt_merge/mem_mem_RAMREG_4_G[27]_s0/CE | clk_sys:[R] | clk_sys:[R] | 20.000 | -0.008 | 19.162
18 | 0.566 | g_sound.u_evt_merge/cnt_q_0_s0/Q | g_sound.u_evt_merge/mem_mem_RAMREG_4_G[22]_s0/CE | clk_sys:[R] | clk_sys:[R] | 20.000 | -0.008 | 19.162
19 | 0.582 | g_sound.u_adc_farm/u_scan0/sample_channel_0_s0/Q | g_sound.u_calib1/n840_s/A[2] | clk_sys:[R] | clk_sys:[R] | 20.000 | 0.008 | 16.009
20 | 0.588 | g_sound.u_evt_merge/cnt_q_0_s0/Q | g_sound.u_evt_merge/mem_mem_RAMREG_4_G[48]_s0/CE | clk_sys:[R] | clk_sys:[R] | 20.000 | 0.000 | 19.132
21 | 0.588 | g_sound.u_evt_merge/cnt_q_0_s0/Q | g_sound.u_evt_merge/mem_mem_RAMREG_4_G[47]_s0/CE | clk_sys:[R] | clk_sys:[R] | 20.000 | 0.000 | 19.132
22 | 0.588 | g_sound.u_evt_merge/cnt_q_0_s0/Q | g_sound.u_evt_merge/mem_mem_RAMREG_4_G[46]_s0/CE | clk_sys:[R] | clk_sys:[R] | 20.000 | 0.000 | 19.132
23 | 0.588 | g_sound.u_evt_merge/cnt_q_0_s0/Q | g_sound.u_evt_merge/mem_mem_RAMREG_4_G[39]_s0/CE | clk_sys:[R] | clk_sys:[R] | 20.000 | 0.000 | 19.132
24 | 0.588 | g_sound.u_evt_merge/cnt_q_0_s0/Q | g_sound.u_evt_merge/mem_mem_RAMREG_4_G[44]_s0/CE | clk_sys:[R] | clk_sys:[R] | 20.000 | -0.008 | 19.141
25 | 0.588 | g_sound.u_evt_merge/cnt_q_0_s0/Q | g_sound.u_evt_merge/mem_mem_RAMREG_4_G[43]_s0/CE | clk_sys:[R] | clk_sys:[R] | 20.000 | -0.008 | 19.141

### Hold Paths Table

#### Report Command:report_timing -hold -max_paths 25 -max_common_paths 1

Path Number | Path Slack | From Node | To Node | From Clock | To Clock | Relation | Clock Skew | Data Delay
1 | 0.127 | g_sound.u_beat_gen/tick_cnt_o_q_4_s0/Q | g_sound.u_drum_gen/tick_at_step_q_4_s0/D | clk_sys:[R] | clk_sys:[R] | 0.000 | -0.181 | 0.260
2 | 0.187 | u_hdmi/u_timing/x_2_s0/Q | u_hdmi/u_scope/frame_y_frame_y_0_0_s/ADB[5] | pixel_clk:[R] | pixel_clk:[R] | 0.000 | 0.000 | 0.219
3 | 0.193 | g_sound.u_beat_gen/tick_cnt_o_q_7_s0/Q | g_sound.u_drum_gen/tick_at_step_q_7_s0/D | clk_sys:[R] | clk_sys:[R] | 0.000 | -0.177 | 0.322
4 | 0.195 | g_sound.u_beat_gen/tick_cnt_o_q_8_s0/Q | g_sound.u_drum_gen/tick_at_step_q_8_s0/D | clk_sys:[R] | clk_sys:[R] | 0.000 | -0.177 | 0.325
5 | 0.195 | g_sound.u_beat_gen/tick_cnt_o_q_10_s0/Q | g_sound.u_drum_gen/tick_at_step_q_10_s0/D | clk_sys:[R] | clk_sys:[R] | 0.000 | -0.177 | 0.325
6 | 0.195 | g_sound.u_beat_gen/tick_cnt_o_q_15_s0/Q | g_sound.u_drum_gen/tick_at_step_q_15_s0/D | clk_sys:[R] | clk_sys:[R] | 0.000 | -0.177 | 0.325
7 | 0.197 | g_sound.u_beat_gen/tick_cnt_o_q_5_s0/Q | g_sound.u_drum_gen/tick_at_step_q_5_s0/D | clk_sys:[R] | clk_sys:[R] | 0.000 | -0.177 | 0.327
8 | 0.198 | g_sound.u_beat_gen/tick_cnt_o_q_13_s0/Q | g_sound.u_drum_gen/tick_at_step_q_13_s0/D | clk_sys:[R] | clk_sys:[R] | 0.000 | -0.177 | 0.328
9 | 0.205 | g_sound.u_beat_gen/tick_cnt_o_q_6_s0/Q | g_sound.u_drum_gen/tick_at_step_q_6_s0/D | clk_sys:[R] | clk_sys:[R] | 0.000 | -0.181 | 0.338
10 | 0.215 | g_sound.u_beat_gen/tick_cnt_o_q_1_s0/Q | g_sound.u_drum_gen/tick_at_step_q_1_s0/D | clk_sys:[R] | clk_sys:[R] | 0.000 | -0.174 | 0.341
11 | 0.221 | g_sound.u_note_manager/fifo_wr_0_s3/Q | g_sound.u_note_manager/fifo_ax_fifo_ax_0_0_s/ADA[5] | clk_sys:[R] | clk_sys:[R] | 0.000 | -0.004 | 0.258
12 | 0.227 | u_hdmi/u_scope/copy_index_q_6_s0/Q | u_hdmi/u_scope/frame_y_frame_y_0_0_s/ADA[9] | pixel_clk:[R] | pixel_clk:[R] | 0.000 | 0.000 | 0.260
13 | 0.234 | g_sound.u_looper/play_inc_o_3_s0/Q | g_sound.u_evt_merge/mem_mem_RAMREG_0_G[16]_s0/D | clk_sys:[R] | clk_sys:[R] | 0.000 | -0.177 | 0.434
14 | 0.247 | u_i2s_tx/bit_cnt_4_s0/Q | u_i2s_tx/bit_cnt_4_s0/D | clk_sys:[R] | clk_sys:[R] | 0.000 | 0.000 | 0.270
15 | 0.247 | u_i2s_tx/ch_s0/Q | u_i2s_tx/ch_s0/D | clk_sys:[R] | clk_sys:[R] | 0.000 | 0.000 | 0.270
16 | 0.247 | g_sound.u_perc_env_bank/gen_perc[4].level_r_0_s0/Q | g_sound.u_perc_env_bank/gen_perc[4].level_r_0_s0/D | clk_sys:[R] | clk_sys:[R] | 0.000 | 0.000 | 0.270
17 | 0.247 | g_sound.u_perc_env_bank/gen_perc[3].level_r_6_s0/Q | g_sound.u_perc_env_bank/gen_perc[3].level_r_6_s0/D | clk_sys:[R] | clk_sys:[R] | 0.000 | 0.000 | 0.270
18 | 0.247 | g_sound.u_perc_env_bank/gen_perc[1].level_r_7_s0/Q | g_sound.u_perc_env_bank/gen_perc[1].level_r_7_s0/D | clk_sys:[R] | clk_sys:[R] | 0.000 | 0.000 | 0.270
19 | 0.247 | g_sound.u_perc_env_bank/gen_perc[0].level_r_7_s0/Q | g_sound.u_perc_env_bank/gen_perc[0].level_r_7_s0/D | clk_sys:[R] | clk_sys:[R] | 0.000 | 0.000 | 0.270
20 | 0.247 | g_sound.u_oscillator_bank/gen_lane[58].phase_q_31_s0/Q | g_sound.u_oscillator_bank/gen_lane[58].phase_q_31_s0/D | clk_sys:[R] | clk_sys:[R] | 0.000 | 0.000 | 0.270
21 | 0.247 | g_sound.u_oscillator_bank/gen_lane[56].phase_q_31_s0/Q | g_sound.u_oscillator_bank/gen_lane[56].phase_q_31_s0/D | clk_sys:[R] | clk_sys:[R] | 0.000 | 0.000 | 0.270
22 | 0.247 | g_sound.u_oscillator_bank/gen_lane[55].phase_q_31_s0/Q | g_sound.u_oscillator_bank/gen_lane[55].phase_q_31_s0/D | clk_sys:[R] | clk_sys:[R] | 0.000 | 0.000 | 0.270
23 | 0.247 | g_sound.u_oscillator_bank/gen_lane[54].phase_q_31_s0/Q | g_sound.u_oscillator_bank/gen_lane[54].phase_q_31_s0/D | clk_sys:[R] | clk_sys:[R] | 0.000 | 0.000 | 0.270
24 | 0.247 | g_sound.u_oscillator_bank/gen_lane[53].phase_q_31_s0/Q | g_sound.u_oscillator_bank/gen_lane[53].phase_q_31_s0/D | clk_sys:[R] | clk_sys:[R] | 0.000 | 0.000 | 0.270
25 | 0.247 | g_sound.u_oscillator_bank/gen_lane[52].phase_q_31_s0/Q | g_sound.u_oscillator_bank/gen_lane[52].phase_q_31_s0/D | clk_sys:[R] | clk_sys:[R] | 0.000 | 0.000 | 0.270

### Recovery Paths Table

#### Report Command:report_timing -recovery -max_paths 25 -max_common_paths 1

Path Number | Path Slack | From Node | To Node | From Clock | To Clock | Relation | Clock Skew | Data Delay
1 | 1.481 | u_rst_sync/sync_chain_1_s0/Q | u_hdmi/u_serializer/lanes[3].u_oser/RESET | clk_sys:[R] | serial_clk:[R] | 4.000 | 0.000 | 2.347
2 | 1.481 | u_rst_sync/sync_chain_1_s0/Q | u_hdmi/u_serializer/lanes[2].u_oser/RESET | clk_sys:[R] | serial_clk:[R] | 4.000 | 0.000 | 2.347
3 | 1.481 | u_rst_sync/sync_chain_1_s0/Q | u_hdmi/u_serializer/lanes[1].u_oser/RESET | clk_sys:[R] | serial_clk:[R] | 4.000 | 0.000 | 2.347
4 | 1.481 | u_rst_sync/sync_chain_1_s0/Q | u_hdmi/u_serializer/lanes[0].u_oser/RESET | clk_sys:[R] | serial_clk:[R] | 4.000 | 0.000 | 2.347
5 | 1.482 | u_rst_sync/sync_chain_1_s0/Q | u_hdmi/u_serializer/lanes[0].u_oser/RESET | clk_sys:[R] | serial_clk:[F] | 4.000 | 0.000 | 2.347
6 | 1.482 | u_rst_sync/sync_chain_1_s0/Q | u_hdmi/u_serializer/lanes[1].u_oser/RESET | clk_sys:[R] | serial_clk:[F] | 4.000 | 0.000 | 2.347
7 | 1.482 | u_rst_sync/sync_chain_1_s0/Q | u_hdmi/u_serializer/lanes[2].u_oser/RESET | clk_sys:[R] | serial_clk:[F] | 4.000 | 0.000 | 2.347
8 | 1.482 | u_rst_sync/sync_chain_1_s0/Q | u_hdmi/u_serializer/lanes[3].u_oser/RESET | clk_sys:[R] | serial_clk:[F] | 4.000 | 0.000 | 2.347
9 | 11.807 | u_rst_sync/sync_chain_1_s0/Q | g_sound.u_calib0/n840_s/RESET[0] | clk_sys:[R] | clk_sys:[R] | 20.000 | -0.008 | 7.696
10 | 12.725 | u_rst_sync/sync_chain_1_s0/Q | g_sound.u_calib1/n840_s/RESET[0] | clk_sys:[R] | clk_sys:[R] | 20.000 | 0.000 | 6.770
11 | 17.334 | u_rst_sync/sync_chain_1_s0/Q | g_sound.u_looper/on_addr_r[13]_9_s0/CLEAR | clk_sys:[R] | clk_sys:[R] | 20.000 | 0.000 | 2.353
12 | 17.334 | u_rst_sync/sync_chain_1_s0/Q | g_sound.u_looper/on_addr_r[9]_0_s0/CLEAR | clk_sys:[R] | clk_sys:[R] | 20.000 | 0.000 | 2.353
13 | 17.334 | u_rst_sync/sync_chain_1_s0/Q | g_sound.u_looper/last_inc_r[13]_14_s0/CLEAR | clk_sys:[R] | clk_sys:[R] | 20.000 | 0.000 | 2.353
14 | 17.334 | u_rst_sync/sync_chain_1_s0/Q | g_sound.u_looper/last_inc_r[5]_11_s0/CLEAR | clk_sys:[R] | clk_sys:[R] | 20.000 | 0.000 | 2.353
15 | 17.334 | u_rst_sync/sync_chain_1_s0/Q | g_sound.u_looper/last_inc_r[5]_14_s0/CLEAR | clk_sys:[R] | clk_sys:[R] | 20.000 | 0.000 | 2.353
16 | 17.334 | u_rst_sync/sync_chain_1_s0/Q | g_sound.u_looper/last_inc_r[0]_11_s0/CLEAR | clk_sys:[R] | clk_sys:[R] | 20.000 | 0.000 | 2.353
17 | 17.334 | u_rst_sync/sync_chain_1_s0/Q | g_sound.u_looper/last_inc_r[0]_12_s0/CLEAR | clk_sys:[R] | clk_sys:[R] | 20.000 | 0.000 | 2.353
18 | 17.334 | u_rst_sync/sync_chain_1_s0/Q | g_sound.u_looper/last_inc_r[0]_13_s0/CLEAR | clk_sys:[R] | clk_sys:[R] | 20.000 | 0.000 | 2.353
19 | 17.334 | u_rst_sync/sync_chain_1_s0/Q | g_sound.u_looper/play_inc_o_1_s0/CLEAR | clk_sys:[R] | clk_sys:[R] | 20.000 | 0.000 | 2.353
20 | 17.334 | u_rst_sync/sync_chain_1_s0/Q | g_sound.u_looper/play_inc_o_5_s0/CLEAR | clk_sys:[R] | clk_sys:[R] | 20.000 | 0.000 | 2.353
21 | 17.334 | u_rst_sync/sync_chain_1_s0/Q | g_sound.u_looper/play_inc_o_11_s0/CLEAR | clk_sys:[R] | clk_sys:[R] | 20.000 | 0.000 | 2.353
22 | 17.334 | u_rst_sync/sync_chain_1_s0/Q | g_sound.u_looper/play_inc_o_14_s0/CLEAR | clk_sys:[R] | clk_sys:[R] | 20.000 | 0.000 | 2.353
23 | 17.334 | u_rst_sync/sync_chain_1_s0/Q | g_sound.u_looper/play_inc_o_19_s0/CLEAR | clk_sys:[R] | clk_sys:[R] | 20.000 | 0.000 | 2.353
24 | 17.334 | u_rst_sync/sync_chain_1_s0/Q | g_sound.u_looper/play_inc_o_20_s0/CLEAR | clk_sys:[R] | clk_sys:[R] | 20.000 | 0.000 | 2.353
25 | 17.334 | u_rst_sync/sync_chain_1_s0/Q | g_sound.u_looper/play_inc_o_21_s0/CLEAR | clk_sys:[R] | clk_sys:[R] | 20.000 | 0.000 | 2.353

### Removal Paths Table

#### Report Command:report_timing -removal -max_paths 25 -max_common_paths 1

Path Number | Path Slack | From Node | To Node | From Clock | To Clock | Relation | Clock Skew | Data Delay
1 | 0.223 | u_rst_sync/sync_chain_1_s0/Q | u_hdmi/u_serializer/lanes[3].u_oser/RESET | clk_sys:[R] | pixel_clk:[R] | 0.000 | -0.612 | 1.008
2 | 0.223 | u_rst_sync/sync_chain_1_s0/Q | u_hdmi/u_serializer/lanes[2].u_oser/RESET | clk_sys:[R] | pixel_clk:[R] | 0.000 | -0.612 | 1.008
3 | 0.223 | u_rst_sync/sync_chain_1_s0/Q | u_hdmi/u_serializer/lanes[1].u_oser/RESET | clk_sys:[R] | pixel_clk:[R] | 0.000 | -0.612 | 1.008
4 | 0.223 | u_rst_sync/sync_chain_1_s0/Q | u_hdmi/u_serializer/lanes[0].u_oser/RESET | clk_sys:[R] | pixel_clk:[R] | 0.000 | -0.612 | 1.008
5 | 0.408 | u_rst_sync/sync_chain_1_s0/Q | u_hdmi/reset_pipe_1_s0/CLEAR | clk_sys:[R] | pixel_clk:[R] | 0.000 | -0.609 | 1.004
6 | 0.408 | u_rst_sync/sync_chain_1_s0/Q | u_hdmi/reset_pipe_0_s0/CLEAR | clk_sys:[R] | pixel_clk:[R] | 0.000 | -0.609 | 1.004
7 | 0.835 | u_rst_sync/sync_chain_1_s0/Q | u_hdmi/u_serializer/lanes[0].u_oser/RESET | clk_sys:[R] | serial_clk:[R] | 0.000 | 0.000 | 1.008
8 | 0.835 | u_rst_sync/sync_chain_1_s0/Q | u_hdmi/u_serializer/lanes[1].u_oser/RESET | clk_sys:[R] | serial_clk:[R] | 0.000 | 0.000 | 1.008
9 | 0.835 | u_rst_sync/sync_chain_1_s0/Q | u_hdmi/u_serializer/lanes[2].u_oser/RESET | clk_sys:[R] | serial_clk:[R] | 0.000 | 0.000 | 1.008
10 | 0.835 | u_rst_sync/sync_chain_1_s0/Q | u_hdmi/u_serializer/lanes[3].u_oser/RESET | clk_sys:[R] | serial_clk:[R] | 0.000 | 0.000 | 1.008
11 | 0.837 | u_rst_sync/sync_chain_1_s0/Q | u_hdmi/u_serializer/lanes[0].u_oser/RESET | clk_sys:[R] | serial_clk:[F] | 0.000 | 0.000 | 1.008
12 | 0.837 | u_rst_sync/sync_chain_1_s0/Q | u_hdmi/u_serializer/lanes[1].u_oser/RESET | clk_sys:[R] | serial_clk:[F] | 0.000 | 0.000 | 1.008
13 | 0.837 | u_rst_sync/sync_chain_1_s0/Q | u_hdmi/u_serializer/lanes[2].u_oser/RESET | clk_sys:[R] | serial_clk:[F] | 0.000 | 0.000 | 1.008
14 | 0.837 | u_rst_sync/sync_chain_1_s0/Q | u_hdmi/u_serializer/lanes[3].u_oser/RESET | clk_sys:[R] | serial_clk:[F] | 0.000 | 0.000 | 1.008
15 | 0.868 | u_rst_sync/sync_chain_1_s0/Q | g_sound.u_looper/last_inc_r[3]_4_s0/CLEAR | clk_sys:[R] | clk_sys:[R] | 0.000 | -0.185 | 1.005
16 | 0.868 | u_rst_sync/sync_chain_1_s0/Q | g_sound.u_looper/last_inc_r[3]_23_s0/CLEAR | clk_sys:[R] | clk_sys:[R] | 0.000 | -0.185 | 1.005
17 | 0.876 | u_rst_sync/sync_chain_1_s0/Q | g_sound.u_looper/last_inc_r[11]_4_s0/CLEAR | clk_sys:[R] | clk_sys:[R] | 0.000 | -0.181 | 1.009
18 | 0.876 | u_rst_sync/sync_chain_1_s0/Q | g_sound.u_looper/last_inc_r[11]_23_s0/CLEAR | clk_sys:[R] | clk_sys:[R] | 0.000 | -0.181 | 1.009
19 | 0.885 | u_rst_sync/sync_chain_1_s0/Q | g_sound.u_looper/play_valid_o_s0/CLEAR | clk_sys:[R] | clk_sys:[R] | 0.000 | -0.181 | 1.018
20 | 0.888 | u_rst_sync/sync_chain_1_s0/Q | g_sound.u_calib1/quo_r_15_s1/CLEAR | clk_sys:[R] | clk_sys:[R] | 0.000 | -0.185 | 1.025
21 | 0.888 | u_rst_sync/sync_chain_1_s0/Q | g_sound.u_calib1/rem_r_3_s1/CLEAR | clk_sys:[R] | clk_sys:[R] | 0.000 | -0.185 | 1.025
22 | 0.888 | u_rst_sync/sync_chain_1_s0/Q | g_sound.u_calib1/rem_r_4_s1/CLEAR | clk_sys:[R] | clk_sys:[R] | 0.000 | -0.185 | 1.025
23 | 0.888 | u_rst_sync/sync_chain_1_s0/Q | g_sound.u_calib1/rem_r_5_s1/CLEAR | clk_sys:[R] | clk_sys:[R] | 0.000 | -0.185 | 1.025
24 | 0.888 | u_rst_sync/sync_chain_1_s0/Q | g_sound.u_calib1/rem_r_6_s1/CLEAR | clk_sys:[R] | clk_sys:[R] | 0.000 | -0.185 | 1.025
25 | 0.888 | u_rst_sync/sync_chain_1_s0/Q | g_sound.u_calib1/rem_r_7_s1/CLEAR | clk_sys:[R] | clk_sys:[R] | 0.000 | -0.185 | 1.025

## Minimum Pulse Width Table:

Number | Slack | Actual Width | Required Width | Type | Clock | Objects

#### Report Command:report_min_pulse_width -nworst 10 -detail

1 | 6.809 | 7.709 | 0.900 | Low Pulse Width | clk_sys | g_sound.u_looper/ep_mem_ep_mem_0_3_s
2 | 6.809 | 7.709 | 0.900 | Low Pulse Width | clk_sys | g_sound.u_looper/ep_mem_ep_mem_0_4_s
3 | 6.814 | 7.714 | 0.900 | Low Pulse Width | clk_sys | g_sound.u_looper/ep_mem_ep_mem_0_3_s
4 | 6.814 | 7.714 | 0.900 | Low Pulse Width | clk_sys | g_sound.u_looper/ep_mem_ep_mem_0_4_s
5 | 7.072 | 7.972 | 0.900 | Low Pulse Width | clk_sys | g_sound.u_envelope_bank/g_voice_envelope[6].u_adsr/n103_s
6 | 7.072 | 7.972 | 0.900 | Low Pulse Width | clk_sys | g_sound.u_envelope_bank/g_voice_envelope[9].u_adsr/n103_s
7 | 7.074 | 7.974 | 0.900 | Low Pulse Width | clk_sys | g_sound.u_tdm_render_mixer/mult_14924_0_s
8 | 7.074 | 7.974 | 0.900 | Low Pulse Width | clk_sys | g_sound.u_tdm_render_mixer/mult_14936_0_s
9 | 7.077 | 7.977 | 0.900 | Low Pulse Width | clk_sys | g_sound.u_envelope_bank/g_voice_envelope[16].u_adsr/n103_s
10 | 7.077 | 7.977 | 0.900 | Low Pulse Width | clk_sys | g_sound.u_envelope_bank/g_voice_envelope[18].u_adsr/n103_s

## Timing Report By Analysis Type:

### Setup Analysis Report

#### Report Command:report_timing -setup -max_paths 25 -max_common_paths 1

### Path1

Path Summary:

Slack | 0.194
Data Arrival Time | 24.113
Data Required Time | 24.307
From | g_sound.u_evt_merge/cnt_q_0_s0
To | g_sound.u_evt_merge/mem_mem_RAMREG_1_G[48]_s0
Launch Clk | clk_sys:[R]
Latch Clk | clk_sys:[R]

Data Arrival Path:

AT | DELAY | TYPE | RF | FANOUT | LOC | NODE
0.000 | 0.000 | | | | | active clock edge time
0.000 | 0.000 | | | | | clk_sys
0.000 | 0.000 | tCL | RR | 1 | IOB117[B] | clk_ibuf/I
1.288 | 1.288 | tINS | RR | 15774 | IOB117[B] | clk_ibuf/O
4.579 | 3.291 | tNET | RR | 1 | R37C18[2][A] | g_sound.u_evt_merge/cnt_q_0_s0/CLK
4.923 | 0.344 | tC2Q | RR | 6 | R37C18[2][A] | g_sound.u_evt_merge/cnt_q_0_s0/Q
5.276 | 0.353 | tNET | RR | 1 | R33C18[0][A] | g_sound.u_evt_merge/cnt_after_pop_5_s1/I0
5.750 | 0.474 | tINS | RR | 5 | R33C18[0][A] | g_sound.u_evt_merge/cnt_after_pop_5_s1/F
6.067 | 0.317 | tNET | RR | 1 | R33C16[1][B] | g_sound.u_evt_merge/cnt_after_pop_8_s1/I3
6.541 | 0.474 | tINS | RR | 5 | R33C16[1][B] | g_sound.u_evt_merge/cnt_after_pop_8_s1/F
6.692 | 0.151 | tNET | RR | 1 | R33C17[1][A] | g_sound.u_evt_merge/cnt_after_pop_11_s1/I3
7.107 | 0.415 | tINS | RR | 5 | R33C17[1][A] | g_sound.u_evt_merge/cnt_after_pop_11_s1/F
7.255 | 0.149 | tNET | RR | 1 | R33C18[2][A] | g_sound.u_evt_merge/cnt_after_pop_13_s2/I3
7.670 | 0.415 | tINS | RR | 5 | R33C18[2][A] | g_sound.u_evt_merge/cnt_after_pop_13_s2/F
8.145 | 0.475 | tNET | RR | 1 | R33C15[0][A] | g_sound.u_evt_merge/pop_now_s2/I3
8.381 | 0.236 | tINS | RR | 89 | R33C15[0][A] | g_sound.u_evt_merge/pop_now_s2/F
12.717 | 4.336 | tNET | RR | 1 | R34C16[0][B] | g_sound.u_evt_merge/cnt_after_pop_1_s0/I1
12.953 | 0.236 | tINS | RR | 2 | R34C16[0][B] | g_sound.u_evt_merge/cnt_after_pop_1_s0/F
13.300 | 0.346 | tNET | RR | 2 | R37C16[0][B] | g_sound.u_evt_merge/cnt_next_1_s/I0
13.806 | 0.506 | tINS | RF | 1 | R37C16[0][B] | g_sound.u_evt_merge/cnt_next_1_s/COUT
13.806 | 0.000 | tNET | FF | 2 | R37C16[1][A] | g_sound.u_evt_merge/cnt_next_2_s/CIN
13.851 | 0.045 | tINS | FR | 1 | R37C16[1][A] | g_sound.u_evt_merge/cnt_next_2_s/COUT
13.851 | 0.000 | tNET | RR | 2 | R37C16[1][B] | g_sound.u_evt_merge/cnt_next_3_s/CIN
13.896 | 0.045 | tINS | RR | 1 | R37C16[1][B] | g_sound.u_evt_merge/cnt_next_3_s/COUT
13.896 | 0.000 | tNET | RR | 2 | R37C16[2][A] | g_sound.u_evt_merge/cnt_next_4_s/CIN
13.941 | 0.045 | tINS | RR | 1 | R37C16[2][A] | g_sound.u_evt_merge/cnt_next_4_s/COUT
13.941 | 0.000 | tNET | RR | 2 | R37C16[2][B] | g_sound.u_evt_merge/cnt_next_5_s/CIN
13.986 | 0.045 | tINS | RR | 1 | R37C16[2][B] | g_sound.u_evt_merge/cnt_next_5_s/COUT
13.986 | 0.000 | tNET | RR | 2 | R37C17[0][A] | g_sound.u_evt_merge/cnt_next_6_s/CIN
14.031 | 0.045 | tINS | RR | 1 | R37C17[0][A] | g_sound.u_evt_merge/cnt_next_6_s/COUT
14.031 | 0.000 | tNET | RR | 2 | R37C17[0][B] | g_sound.u_evt_merge/cnt_next_7_s/CIN
14.298 | 0.267 | tINS | RR | 1 | R37C17[0][B] | g_sound.u_evt_merge/cnt_next_7_s/SUM
14.422 | 0.124 | tNET | RR | 1 | R37C17[3][B] | g_sound.u_evt_merge/n1433_s4/I3
14.869 | 0.448 | tINS | RR | 1 | R37C17[3][B] | g_sound.u_evt_merge/n1433_s4/F
15.011 | 0.142 | tNET | RR | 1 | R37C16[3][A] | g_sound.u_evt_merge/n1433_s3/I2
15.480 | 0.469 | tINS | RR | 1 | R37C16[3][A] | g_sound.u_evt_merge/n1433_s3/F
15.622 | 0.142 | tNET | RR | 1 | R37C15[3][B] | g_sound.u_evt_merge/n1433_s2/I2
16.070 | 0.448 | tINS | RR | 1 | R37C15[3][B] | g_sound.u_evt_merge/n1433_s2/F
16.072 | 0.002 | tNET | RR | 1 | R37C15[2][A] | g_sound.u_evt_merge/n1433_s1/I3
16.546 | 0.474 | tINS | RR | 1 | R37C15[2][A] | g_sound.u_evt_merge/n1433_s1/F
16.858 | 0.313 | tNET | RR | 1 | R37C18[2][B] | g_sound.u_evt_merge/n1433_s0/I3
17.273 | 0.415 | tINS | RR | 38 | R37C18[2][B] | g_sound.u_evt_merge/n1433_s0/F
18.106 | 0.833 | tNET | RR | 1 | R35C6[0][A] | g_sound.u_evt_merge/mem_s3593/I3
18.571 | 0.465 | tINS | RR | 1 | R35C6[0][A] | g_sound.u_evt_merge/mem_s3593/F
18.915 | 0.344 | tNET | RR | 1 | R31C6[1][B] | g_sound.u_evt_merge/mem_s3570/I2
19.379 | 0.465 | tINS | RR | 8 | R31C6[1][B] | g_sound.u_evt_merge/mem_s3570/F
19.832 | 0.452 | tNET | RR | 1 | R31C12[2][A] | g_sound.u_evt_merge/mem_s3546/I2
20.296 | 0.465 | tINS | RR | 70 | R31C12[2][A] | g_sound.u_evt_merge/mem_s3546/F
20.881 | 0.585 | tNET | RR | 1 | R31C8[2][B] | g_sound.u_evt_merge/mem_s3663/I3
21.118 | 0.236 | tINS | RR | 13 | R31C8[2][B] | g_sound.u_evt_merge/mem_s3663/F
21.487 | 0.369 | tNET | RR | 1 | R31C11[2][B] | g_sound.u_evt_merge/mem_s3075/I1
21.960 | 0.474 | tINS | RR | 50 | R31C11[2][B] | g_sound.u_evt_merge/mem_s3075/F
24.113 | 2.153 | tNET | RR | 1 | R35C21[1][B] | g_sound.u_evt_merge/mem_mem_RAMREG_1_G[48]_s0/CE

Data Required Path:

AT | DELAY | TYPE | RF | FANOUT | LOC | NODE
20.000 | 20.000 | | | | | active clock edge time
20.000 | 0.000 | | | | | clk_sys
20.000 | 0.000 | tCL | RR | 1 | IOB117[B] | clk_ibuf/I
21.288 | 1.288 | tINS | RR | 15774 | IOB117[B] | clk_ibuf/O
24.587 | 3.299 | tNET | RR | 1 | R35C21[1][B] | g_sound.u_evt_merge/mem_mem_RAMREG_1_G[48]_s0/CLK
24.307 | -0.280 | tSu | | 1 | R35C21[1][B] | g_sound.u_evt_merge/mem_mem_RAMREG_1_G[48]_s0

Path Statistics:

Clock Skew | 0.008
Setup Relationship | 20.000
Logic Level | 20
Arrival Clock Path Delay | cell: 1.288, 28.136%; route: 3.291, 71.864%
Arrival Data Path Delay | cell: 7.605, 38.932%; route: 11.585, 59.305%; tC2Q: 0.344, 1.762%
Required Clock Path Delay | cell: 1.288, 28.084%; route: 3.299, 71.916%

### Path2

Path Summary:

Slack | 0.194
Data Arrival Time | 24.113
Data Required Time | 24.307
From | g_sound.u_evt_merge/cnt_q_0_s0
To | g_sound.u_evt_merge/mem_mem_RAMREG_1_G[44]_s0
Launch Clk | clk_sys:[R]
Latch Clk | clk_sys:[R]

Data Arrival Path:

AT | DELAY | TYPE | RF | FANOUT | LOC | NODE
0.000 | 0.000 | | | | | active clock edge time
0.000 | 0.000 | | | | | clk_sys
0.000 | 0.000 | tCL | RR | 1 | IOB117[B] | clk_ibuf/I
1.288 | 1.288 | tINS | RR | 15774 | IOB117[B] | clk_ibuf/O
4.579 | 3.291 | tNET | RR | 1 | R37C18[2][A] | g_sound.u_evt_merge/cnt_q_0_s0/CLK
4.923 | 0.344 | tC2Q | RR | 6 | R37C18[2][A] | g_sound.u_evt_merge/cnt_q_0_s0/Q
5.276 | 0.353 | tNET | RR | 1 | R33C18[0][A] | g_sound.u_evt_merge/cnt_after_pop_5_s1/I0
5.750 | 0.474 | tINS | RR | 5 | R33C18[0][A] | g_sound.u_evt_merge/cnt_after_pop_5_s1/F
6.067 | 0.317 | tNET | RR | 1 | R33C16[1][B] | g_sound.u_evt_merge/cnt_after_pop_8_s1/I3
6.541 | 0.474 | tINS | RR | 5 | R33C16[1][B] | g_sound.u_evt_merge/cnt_after_pop_8_s1/F
6.692 | 0.151 | tNET | RR | 1 | R33C17[1][A] | g_sound.u_evt_merge/cnt_after_pop_11_s1/I3
7.107 | 0.415 | tINS | RR | 5 | R33C17[1][A] | g_sound.u_evt_merge/cnt_after_pop_11_s1/F
7.255 | 0.149 | tNET | RR | 1 | R33C18[2][A] | g_sound.u_evt_merge/cnt_after_pop_13_s2/I3
7.670 | 0.415 | tINS | RR | 5 | R33C18[2][A] | g_sound.u_evt_merge/cnt_after_pop_13_s2/F
8.145 | 0.475 | tNET | RR | 1 | R33C15[0][A] | g_sound.u_evt_merge/pop_now_s2/I3
8.381 | 0.236 | tINS | RR | 89 | R33C15[0][A] | g_sound.u_evt_merge/pop_now_s2/F
12.717 | 4.336 | tNET | RR | 1 | R34C16[0][B] | g_sound.u_evt_merge/cnt_after_pop_1_s0/I1
12.953 | 0.236 | tINS | RR | 2 | R34C16[0][B] | g_sound.u_evt_merge/cnt_after_pop_1_s0/F
13.300 | 0.346 | tNET | RR | 2 | R37C16[0][B] | g_sound.u_evt_merge/cnt_next_1_s/I0
13.806 | 0.506 | tINS | RF | 1 | R37C16[0][B] | g_sound.u_evt_merge/cnt_next_1_s/COUT
13.806 | 0.000 | tNET | FF | 2 | R37C16[1][A] | g_sound.u_evt_merge/cnt_next_2_s/CIN
13.851 | 0.045 | tINS | FR | 1 | R37C16[1][A] | g_sound.u_evt_merge/cnt_next_2_s/COUT
13.851 | 0.000 | tNET | RR | 2 | R37C16[1][B] | g_sound.u_evt_merge/cnt_next_3_s/CIN
13.896 | 0.045 | tINS | RR | 1 | R37C16[1][B] | g_sound.u_evt_merge/cnt_next_3_s/COUT
13.896 | 0.000 | tNET | RR | 2 | R37C16[2][A] | g_sound.u_evt_merge/cnt_next_4_s/CIN
13.941 | 0.045 | tINS | RR | 1 | R37C16[2][A] | g_sound.u_evt_merge/cnt_next_4_s/COUT
13.941 | 0.000 | tNET | RR | 2 | R37C16[2][B] | g_sound.u_evt_merge/cnt_next_5_s/CIN
13.986 | 0.045 | tINS | RR | 1 | R37C16[2][B] | g_sound.u_evt_merge/cnt_next_5_s/COUT
13.986 | 0.000 | tNET | RR | 2 | R37C17[0][A] | g_sound.u_evt_merge/cnt_next_6_s/CIN
14.031 | 0.045 | tINS | RR | 1 | R37C17[0][A] | g_sound.u_evt_merge/cnt_next_6_s/COUT
14.031 | 0.000 | tNET | RR | 2 | R37C17[0][B] | g_sound.u_evt_merge/cnt_next_7_s/CIN
14.298 | 0.267 | tINS | RR | 1 | R37C17[0][B] | g_sound.u_evt_merge/cnt_next_7_s/SUM
14.422 | 0.124 | tNET | RR | 1 | R37C17[3][B] | g_sound.u_evt_merge/n1433_s4/I3
14.869 | 0.448 | tINS | RR | 1 | R37C17[3][B] | g_sound.u_evt_merge/n1433_s4/F
15.011 | 0.142 | tNET | RR | 1 | R37C16[3][A] | g_sound.u_evt_merge/n1433_s3/I2
15.480 | 0.469 | tINS | RR | 1 | R37C16[3][A] | g_sound.u_evt_merge/n1433_s3/F
15.622 | 0.142 | tNET | RR | 1 | R37C15[3][B] | g_sound.u_evt_merge/n1433_s2/I2
16.070 | 0.448 | tINS | RR | 1 | R37C15[3][B] | g_sound.u_evt_merge/n1433_s2/F
16.072 | 0.002 | tNET | RR | 1 | R37C15[2][A] | g_sound.u_evt_merge/n1433_s1/I3
16.546 | 0.474 | tINS | RR | 1 | R37C15[2][A] | g_sound.u_evt_merge/n1433_s1/F
16.858 | 0.313 | tNET | RR | 1 | R37C18[2][B] | g_sound.u_evt_merge/n1433_s0/I3
17.273 | 0.415 | tINS | RR | 38 | R37C18[2][B] | g_sound.u_evt_merge/n1433_s0/F
18.106 | 0.833 | tNET | RR | 1 | R35C6[0][A] | g_sound.u_evt_merge/mem_s3593/I3
18.571 | 0.465 | tINS | RR | 1 | R35C6[0][A] | g_sound.u_evt_merge/mem_s3593/F
18.915 | 0.344 | tNET | RR | 1 | R31C6[1][B] | g_sound.u_evt_merge/mem_s3570/I2
19.379 | 0.465 | tINS | RR | 8 | R31C6[1][B] | g_sound.u_evt_merge/mem_s3570/F
19.832 | 0.452 | tNET | RR | 1 | R31C12[2][A] | g_sound.u_evt_merge/mem_s3546/I2
20.296 | 0.465 | tINS | RR | 70 | R31C12[2][A] | g_sound.u_evt_merge/mem_s3546/F
20.881 | 0.585 | tNET | RR | 1 | R31C8[2][B] | g_sound.u_evt_merge/mem_s3663/I3
21.118 | 0.236 | tINS | RR | 13 | R31C8[2][B] | g_sound.u_evt_merge/mem_s3663/F
21.487 | 0.369 | tNET | RR | 1 | R31C11[2][B] | g_sound.u_evt_merge/mem_s3075/I1
21.960 | 0.474 | tINS | RR | 50 | R31C11[2][B] | g_sound.u_evt_merge/mem_s3075/F
24.113 | 2.153 | tNET | RR | 1 | R34C21[0][B] | g_sound.u_evt_merge/mem_mem_RAMREG_1_G[44]_s0/CE

Data Required Path:

AT | DELAY | TYPE | RF | FANOUT | LOC | NODE
20.000 | 20.000 | | | | | active clock edge time
20.000 | 0.000 | | | | | clk_sys
20.000 | 0.000 | tCL | RR | 1 | IOB117[B] | clk_ibuf/I
21.288 | 1.288 | tINS | RR | 15774 | IOB117[B] | clk_ibuf/O
24.587 | 3.299 | tNET | RR | 1 | R34C21[0][B] | g_sound.u_evt_merge/mem_mem_RAMREG_1_G[44]_s0/CLK
24.307 | -0.280 | tSu | | 1 | R34C21[0][B] | g_sound.u_evt_merge/mem_mem_RAMREG_1_G[44]_s0

Path Statistics:

Clock Skew | 0.008
Setup Relationship | 20.000
Logic Level | 20
Arrival Clock Path Delay | cell: 1.288, 28.136%; route: 3.291, 71.864%
Arrival Data Path Delay | cell: 7.605, 38.932%; route: 11.585, 59.305%; tC2Q: 0.344, 1.762%
Required Clock Path Delay | cell: 1.288, 28.084%; route: 3.299, 71.916%

### Path3

Path Summary:

Slack | 0.194
Data Arrival Time | 24.113
Data Required Time | 24.307
From | g_sound.u_evt_merge/cnt_q_0_s0
To | g_sound.u_evt_merge/mem_mem_RAMREG_1_G[42]_s0
Launch Clk | clk_sys:[R]
Latch Clk | clk_sys:[R]

Data Arrival Path:

AT | DELAY | TYPE | RF | FANOUT | LOC | NODE
0.000 | 0.000 | | | | | active clock edge time
0.000 | 0.000 | | | | | clk_sys
0.000 | 0.000 | tCL | RR | 1 | IOB117[B] | clk_ibuf/I
1.288 | 1.288 | tINS | RR | 15774 | IOB117[B] | clk_ibuf/O
4.579 | 3.291 | tNET | RR | 1 | R37C18[2][A] | g_sound.u_evt_merge/cnt_q_0_s0/CLK
4.923 | 0.344 | tC2Q | RR | 6 | R37C18[2][A] | g_sound.u_evt_merge/cnt_q_0_s0/Q
5.276 | 0.353 | tNET | RR | 1 | R33C18[0][A] | g_sound.u_evt_merge/cnt_after_pop_5_s1/I0
5.750 | 0.474 | tINS | RR | 5 | R33C18[0][A] | g_sound.u_evt_merge/cnt_after_pop_5_s1/F
6.067 | 0.317 | tNET | RR | 1 | R33C16[1][B] | g_sound.u_evt_merge/cnt_after_pop_8_s1/I3
6.541 | 0.474 | tINS | RR | 5 | R33C16[1][B] | g_sound.u_evt_merge/cnt_after_pop_8_s1/F
6.692 | 0.151 | tNET | RR | 1 | R33C17[1][A] | g_sound.u_evt_merge/cnt_after_pop_11_s1/I3
7.107 | 0.415 | tINS | RR | 5 | R33C17[1][A] | g_sound.u_evt_merge/cnt_after_pop_11_s1/F
7.255 | 0.149 | tNET | RR | 1 | R33C18[2][A] | g_sound.u_evt_merge/cnt_after_pop_13_s2/I3
7.670 | 0.415 | tINS | RR | 5 | R33C18[2][A] | g_sound.u_evt_merge/cnt_after_pop_13_s2/F
8.145 | 0.475 | tNET | RR | 1 | R33C15[0][A] | g_sound.u_evt_merge/pop_now_s2/I3
8.381 | 0.236 | tINS | RR | 89 | R33C15[0][A] | g_sound.u_evt_merge/pop_now_s2/F
12.717 | 4.336 | tNET | RR | 1 | R34C16[0][B] | g_sound.u_evt_merge/cnt_after_pop_1_s0/I1
12.953 | 0.236 | tINS | RR | 2 | R34C16[0][B] | g_sound.u_evt_merge/cnt_after_pop_1_s0/F
13.300 | 0.346 | tNET | RR | 2 | R37C16[0][B] | g_sound.u_evt_merge/cnt_next_1_s/I0
13.806 | 0.506 | tINS | RF | 1 | R37C16[0][B] | g_sound.u_evt_merge/cnt_next_1_s/COUT
13.806 | 0.000 | tNET | FF | 2 | R37C16[1][A] | g_sound.u_evt_merge/cnt_next_2_s/CIN
13.851 | 0.045 | tINS | FR | 1 | R37C16[1][A] | g_sound.u_evt_merge/cnt_next_2_s/COUT
13.851 | 0.000 | tNET | RR | 2 | R37C16[1][B] | g_sound.u_evt_merge/cnt_next_3_s/CIN
13.896 | 0.045 | tINS | RR | 1 | R37C16[1][B] | g_sound.u_evt_merge/cnt_next_3_s/COUT
13.896 | 0.000 | tNET | RR | 2 | R37C16[2][A] | g_sound.u_evt_merge/cnt_next_4_s/CIN
13.941 | 0.045 | tINS | RR | 1 | R37C16[2][A] | g_sound.u_evt_merge/cnt_next_4_s/COUT
13.941 | 0.000 | tNET | RR | 2 | R37C16[2][B] | g_sound.u_evt_merge/cnt_next_5_s/CIN
13.986 | 0.045 | tINS | RR | 1 | R37C16[2][B] | g_sound.u_evt_merge/cnt_next_5_s/COUT
13.986 | 0.000 | tNET | RR | 2 | R37C17[0][A] | g_sound.u_evt_merge/cnt_next_6_s/CIN
14.031 | 0.045 | tINS | RR | 1 | R37C17[0][A] | g_sound.u_evt_merge/cnt_next_6_s/COUT
14.031 | 0.000 | tNET | RR | 2 | R37C17[0][B] | g_sound.u_evt_merge/cnt_next_7_s/CIN
14.298 | 0.267 | tINS | RR | 1 | R37C17[0][B] | g_sound.u_evt_merge/cnt_next_7_s/SUM
14.422 | 0.124 | tNET | RR | 1 | R37C17[3][B] | g_sound.u_evt_merge/n1433_s4/I3
14.869 | 0.448 | tINS | RR | 1 | R37C17[3][B] | g_sound.u_evt_merge/n1433_s4/F
15.011 | 0.142 | tNET | RR | 1 | R37C16[3][A] | g_sound.u_evt_merge/n1433_s3/I2
15.480 | 0.469 | tINS | RR | 1 | R37C16[3][A] | g_sound.u_evt_merge/n1433_s3/F
15.622 | 0.142 | tNET | RR | 1 | R37C15[3][B] | g_sound.u_evt_merge/n1433_s2/I2
16.070 | 0.448 | tINS | RR | 1 | R37C15[3][B] | g_sound.u_evt_merge/n1433_s2/F
16.072 | 0.002 | tNET | RR | 1 | R37C15[2][A] | g_sound.u_evt_merge/n1433_s1/I3
16.546 | 0.474 | tINS | RR | 1 | R37C15[2][A] | g_sound.u_evt_merge/n1433_s1/F
16.858 | 0.313 | tNET | RR | 1 | R37C18[2][B] | g_sound.u_evt_merge/n1433_s0/I3
17.273 | 0.415 | tINS | RR | 38 | R37C18[2][B] | g_sound.u_evt_merge/n1433_s0/F
18.106 | 0.833 | tNET | RR | 1 | R35C6[0][A] | g_sound.u_evt_merge/mem_s3593/I3
18.571 | 0.465 | tINS | RR | 1 | R35C6[0][A] | g_sound.u_evt_merge/mem_s3593/F
18.915 | 0.344 | tNET | RR | 1 | R31C6[1][B] | g_sound.u_evt_merge/mem_s3570/I2
19.379 | 0.465 | tINS | RR | 8 | R31C6[1][B] | g_sound.u_evt_merge/mem_s3570/F
19.832 | 0.452 | tNET | RR | 1 | R31C12[2][A] | g_sound.u_evt_merge/mem_s3546/I2
20.296 | 0.465 | tINS | RR | 70 | R31C12[2][A] | g_sound.u_evt_merge/mem_s3546/F
20.881 | 0.585 | tNET | RR | 1 | R31C8[2][B] | g_sound.u_evt_merge/mem_s3663/I3
21.118 | 0.236 | tINS | RR | 13 | R31C8[2][B] | g_sound.u_evt_merge/mem_s3663/F
21.487 | 0.369 | tNET | RR | 1 | R31C11[2][B] | g_sound.u_evt_merge/mem_s3075/I1
21.960 | 0.474 | tINS | RR | 50 | R31C11[2][B] | g_sound.u_evt_merge/mem_s3075/F
24.113 | 2.153 | tNET | RR | 1 | R35C21[0][A] | g_sound.u_evt_merge/mem_mem_RAMREG_1_G[42]_s0/CE

Data Required Path:

AT | DELAY | TYPE | RF | FANOUT | LOC | NODE
20.000 | 20.000 | | | | | active clock edge time
20.000 | 0.000 | | | | | clk_sys
20.000 | 0.000 | tCL | RR | 1 | IOB117[B] | clk_ibuf/I
21.288 | 1.288 | tINS | RR | 15774 | IOB117[B] | clk_ibuf/O
24.587 | 3.299 | tNET | RR | 1 | R35C21[0][A] | g_sound.u_evt_merge/mem_mem_RAMREG_1_G[42]_s0/CLK
24.307 | -0.280 | tSu | | 1 | R35C21[0][A] | g_sound.u_evt_merge/mem_mem_RAMREG_1_G[42]_s0

Path Statistics:

Clock Skew | 0.008
Setup Relationship | 20.000
Logic Level | 20
Arrival Clock Path Delay | cell: 1.288, 28.136%; route: 3.291, 71.864%
Arrival Data Path Delay | cell: 7.605, 38.932%; route: 11.585, 59.305%; tC2Q: 0.344, 1.762%
Required Clock Path Delay | cell: 1.288, 28.084%; route: 3.299, 71.916%

### Path4

Path Summary:

Slack | 0.194
Data Arrival Time | 24.113
Data Required Time | 24.307
From | g_sound.u_evt_merge/cnt_q_0_s0
To | g_sound.u_evt_merge/mem_mem_RAMREG_1_G[41]_s0
Launch Clk | clk_sys:[R]
Latch Clk | clk_sys:[R]

Data Arrival Path:

AT | DELAY | TYPE | RF | FANOUT | LOC | NODE
0.000 | 0.000 | | | | | active clock edge time
0.000 | 0.000 | | | | | clk_sys
0.000 | 0.000 | tCL | RR | 1 | IOB117[B] | clk_ibuf/I
1.288 | 1.288 | tINS | RR | 15774 | IOB117[B] | clk_ibuf/O
4.579 | 3.291 | tNET | RR | 1 | R37C18[2][A] | g_sound.u_evt_merge/cnt_q_0_s0/CLK
4.923 | 0.344 | tC2Q | RR | 6 | R37C18[2][A] | g_sound.u_evt_merge/cnt_q_0_s0/Q
5.276 | 0.353 | tNET | RR | 1 | R33C18[0][A] | g_sound.u_evt_merge/cnt_after_pop_5_s1/I0
5.750 | 0.474 | tINS | RR | 5 | R33C18[0][A] | g_sound.u_evt_merge/cnt_after_pop_5_s1/F
6.067 | 0.317 | tNET | RR | 1 | R33C16[1][B] | g_sound.u_evt_merge/cnt_after_pop_8_s1/I3
6.541 | 0.474 | tINS | RR | 5 | R33C16[1][B] | g_sound.u_evt_merge/cnt_after_pop_8_s1/F
6.692 | 0.151 | tNET | RR | 1 | R33C17[1][A] | g_sound.u_evt_merge/cnt_after_pop_11_s1/I3
7.107 | 0.415 | tINS | RR | 5 | R33C17[1][A] | g_sound.u_evt_merge/cnt_after_pop_11_s1/F
7.255 | 0.149 | tNET | RR | 1 | R33C18[2][A] | g_sound.u_evt_merge/cnt_after_pop_13_s2/I3
7.670 | 0.415 | tINS | RR | 5 | R33C18[2][A] | g_sound.u_evt_merge/cnt_after_pop_13_s2/F
8.145 | 0.475 | tNET | RR | 1 | R33C15[0][A] | g_sound.u_evt_merge/pop_now_s2/I3
8.381 | 0.236 | tINS | RR | 89 | R33C15[0][A] | g_sound.u_evt_merge/pop_now_s2/F
12.717 | 4.336 | tNET | RR | 1 | R34C16[0][B] | g_sound.u_evt_merge/cnt_after_pop_1_s0/I1
12.953 | 0.236 | tINS | RR | 2 | R34C16[0][B] | g_sound.u_evt_merge/cnt_after_pop_1_s0/F
13.300 | 0.346 | tNET | RR | 2 | R37C16[0][B] | g_sound.u_evt_merge/cnt_next_1_s/I0
13.806 | 0.506 | tINS | RF | 1 | R37C16[0][B] | g_sound.u_evt_merge/cnt_next_1_s/COUT
13.806 | 0.000 | tNET | FF | 2 | R37C16[1][A] | g_sound.u_evt_merge/cnt_next_2_s/CIN
13.851 | 0.045 | tINS | FR | 1 | R37C16[1][A] | g_sound.u_evt_merge/cnt_next_2_s/COUT
13.851 | 0.000 | tNET | RR | 2 | R37C16[1][B] | g_sound.u_evt_merge/cnt_next_3_s/CIN
13.896 | 0.045 | tINS | RR | 1 | R37C16[1][B] | g_sound.u_evt_merge/cnt_next_3_s/COUT
13.896 | 0.000 | tNET | RR | 2 | R37C16[2][A] | g_sound.u_evt_merge/cnt_next_4_s/CIN
13.941 | 0.045 | tINS | RR | 1 | R37C16[2][A] | g_sound.u_evt_merge/cnt_next_4_s/COUT
13.941 | 0.000 | tNET | RR | 2 | R37C16[2][B] | g_sound.u_evt_merge/cnt_next_5_s/CIN
13.986 | 0.045 | tINS | RR | 1 | R37C16[2][B] | g_sound.u_evt_merge/cnt_next_5_s/COUT
13.986 | 0.000 | tNET | RR | 2 | R37C17[0][A] | g_sound.u_evt_merge/cnt_next_6_s/CIN
14.031 | 0.045 | tINS | RR | 1 | R37C17[0][A] | g_sound.u_evt_merge/cnt_next_6_s/COUT
14.031 | 0.000 | tNET | RR | 2 | R37C17[0][B] | g_sound.u_evt_merge/cnt_next_7_s/CIN
14.298 | 0.267 | tINS | RR | 1 | R37C17[0][B] | g_sound.u_evt_merge/cnt_next_7_s/SUM
14.422 | 0.124 | tNET | RR | 1 | R37C17[3][B] | g_sound.u_evt_merge/n1433_s4/I3
14.869 | 0.448 | tINS | RR | 1 | R37C17[3][B] | g_sound.u_evt_merge/n1433_s4/F
15.011 | 0.142 | tNET | RR | 1 | R37C16[3][A] | g_sound.u_evt_merge/n1433_s3/I2
15.480 | 0.469 | tINS | RR | 1 | R37C16[3][A] | g_sound.u_evt_merge/n1433_s3/F
15.622 | 0.142 | tNET | RR | 1 | R37C15[3][B] | g_sound.u_evt_merge/n1433_s2/I2
16.070 | 0.448 | tINS | RR | 1 | R37C15[3][B] | g_sound.u_evt_merge/n1433_s2/F
16.072 | 0.002 | tNET | RR | 1 | R37C15[2][A] | g_sound.u_evt_merge/n1433_s1/I3
16.546 | 0.474 | tINS | RR | 1 | R37C15[2][A] | g_sound.u_evt_merge/n1433_s1/F
16.858 | 0.313 | tNET | RR | 1 | R37C18[2][B] | g_sound.u_evt_merge/n1433_s0/I3
17.273 | 0.415 | tINS | RR | 38 | R37C18[2][B] | g_sound.u_evt_merge/n1433_s0/F
18.106 | 0.833 | tNET | RR | 1 | R35C6[0][A] | g_sound.u_evt_merge/mem_s3593/I3
18.571 | 0.465 | tINS | RR | 1 | R35C6[0][A] | g_sound.u_evt_merge/mem_s3593/F
18.915 | 0.344 | tNET | RR | 1 | R31C6[1][B] | g_sound.u_evt_merge/mem_s3570/I2
19.379 | 0.465 | tINS | RR | 8 | R31C6[1][B] | g_sound.u_evt_merge/mem_s3570/F
19.832 | 0.452 | tNET | RR | 1 | R31C12[2][A] | g_sound.u_evt_merge/mem_s3546/I2
20.296 | 0.465 | tINS | RR | 70 | R31C12[2][A] | g_sound.u_evt_merge/mem_s3546/F
20.881 | 0.585 | tNET | RR | 1 | R31C8[2][B] | g_sound.u_evt_merge/mem_s3663/I3
21.118 | 0.236 | tINS | RR | 13 | R31C8[2][B] | g_sound.u_evt_merge/mem_s3663/F
21.487 | 0.369 | tNET | RR | 1 | R31C11[2][B] | g_sound.u_evt_merge/mem_s3075/I1
21.960 | 0.474 | tINS | RR | 50 | R31C11[2][B] | g_sound.u_evt_merge/mem_s3075/F
24.113 | 2.153 | tNET | RR | 1 | R35C21[0][B] | g_sound.u_evt_merge/mem_mem_RAMREG_1_G[41]_s0/CE

Data Required Path:

AT | DELAY | TYPE | RF | FANOUT | LOC | NODE
20.000 | 20.000 | | | | | active clock edge time
20.000 | 0.000 | | | | | clk_sys
20.000 | 0.000 | tCL | RR | 1 | IOB117[B] | clk_ibuf/I
21.288 | 1.288 | tINS | RR | 15774 | IOB117[B] | clk_ibuf/O
24.587 | 3.299 | tNET | RR | 1 | R35C21[0][B] | g_sound.u_evt_merge/mem_mem_RAMREG_1_G[41]_s0/CLK
24.307 | -0.280 | tSu | | 1 | R35C21[0][B] | g_sound.u_evt_merge/mem_mem_RAMREG_1_G[41]_s0

Path Statistics:

Clock Skew | 0.008
Setup Relationship | 20.000
Logic Level | 20
Arrival Clock Path Delay | cell: 1.288, 28.136%; route: 3.291, 71.864%
Arrival Data Path Delay | cell: 7.605, 38.932%; route: 11.585, 59.305%; tC2Q: 0.344, 1.762%
Required Clock Path Delay | cell: 1.288, 28.084%; route: 3.299, 71.916%

### Path5

Path Summary:

Slack | 0.194
Data Arrival Time | 24.113
Data Required Time | 24.307
From | g_sound.u_evt_merge/cnt_q_0_s0
To | g_sound.u_evt_merge/mem_mem_RAMREG_1_G[39]_s0
Launch Clk | clk_sys:[R]
Latch Clk | clk_sys:[R]

Data Arrival Path:

AT | DELAY | TYPE | RF | FANOUT | LOC | NODE
0.000 | 0.000 | | | | | active clock edge time
0.000 | 0.000 | | | | | clk_sys
0.000 | 0.000 | tCL | RR | 1 | IOB117[B] | clk_ibuf/I
1.288 | 1.288 | tINS | RR | 15774 | IOB117[B] | clk_ibuf/O
4.579 | 3.291 | tNET | RR | 1 | R37C18[2][A] | g_sound.u_evt_merge/cnt_q_0_s0/CLK
4.923 | 0.344 | tC2Q | RR | 6 | R37C18[2][A] | g_sound.u_evt_merge/cnt_q_0_s0/Q
5.276 | 0.353 | tNET | RR | 1 | R33C18[0][A] | g_sound.u_evt_merge/cnt_after_pop_5_s1/I0
5.750 | 0.474 | tINS | RR | 5 | R33C18[0][A] | g_sound.u_evt_merge/cnt_after_pop_5_s1/F
6.067 | 0.317 | tNET | RR | 1 | R33C16[1][B] | g_sound.u_evt_merge/cnt_after_pop_8_s1/I3
6.541 | 0.474 | tINS | RR | 5 | R33C16[1][B] | g_sound.u_evt_merge/cnt_after_pop_8_s1/F
6.692 | 0.151 | tNET | RR | 1 | R33C17[1][A] | g_sound.u_evt_merge/cnt_after_pop_11_s1/I3
7.107 | 0.415 | tINS | RR | 5 | R33C17[1][A] | g_sound.u_evt_merge/cnt_after_pop_11_s1/F
7.255 | 0.149 | tNET | RR | 1 | R33C18[2][A] | g_sound.u_evt_merge/cnt_after_pop_13_s2/I3
7.670 | 0.415 | tINS | RR | 5 | R33C18[2][A] | g_sound.u_evt_merge/cnt_after_pop_13_s2/F
8.145 | 0.475 | tNET | RR | 1 | R33C15[0][A] | g_sound.u_evt_merge/pop_now_s2/I3
8.381 | 0.236 | tINS | RR | 89 | R33C15[0][A] | g_sound.u_evt_merge/pop_now_s2/F
12.717 | 4.336 | tNET | RR | 1 | R34C16[0][B] | g_sound.u_evt_merge/cnt_after_pop_1_s0/I1
12.953 | 0.236 | tINS | RR | 2 | R34C16[0][B] | g_sound.u_evt_merge/cnt_after_pop_1_s0/F
13.300 | 0.346 | tNET | RR | 2 | R37C16[0][B] | g_sound.u_evt_merge/cnt_next_1_s/I0
13.806 | 0.506 | tINS | RF | 1 | R37C16[0][B] | g_sound.u_evt_merge/cnt_next_1_s/COUT
13.806 | 0.000 | tNET | FF | 2 | R37C16[1][A] | g_sound.u_evt_merge/cnt_next_2_s/CIN
13.851 | 0.045 | tINS | FR | 1 | R37C16[1][A] | g_sound.u_evt_merge/cnt_next_2_s/COUT
13.851 | 0.000 | tNET | RR | 2 | R37C16[1][B] | g_sound.u_evt_merge/cnt_next_3_s/CIN
13.896 | 0.045 | tINS | RR | 1 | R37C16[1][B] | g_sound.u_evt_merge/cnt_next_3_s/COUT
13.896 | 0.000 | tNET | RR | 2 | R37C16[2][A] | g_sound.u_evt_merge/cnt_next_4_s/CIN
13.941 | 0.045 | tINS | RR | 1 | R37C16[2][A] | g_sound.u_evt_merge/cnt_next_4_s/COUT
13.941 | 0.000 | tNET | RR | 2 | R37C16[2][B] | g_sound.u_evt_merge/cnt_next_5_s/CIN
13.986 | 0.045 | tINS | RR | 1 | R37C16[2][B] | g_sound.u_evt_merge/cnt_next_5_s/COUT
13.986 | 0.000 | tNET | RR | 2 | R37C17[0][A] | g_sound.u_evt_merge/cnt_next_6_s/CIN
14.031 | 0.045 | tINS | RR | 1 | R37C17[0][A] | g_sound.u_evt_merge/cnt_next_6_s/COUT
14.031 | 0.000 | tNET | RR | 2 | R37C17[0][B] | g_sound.u_evt_merge/cnt_next_7_s/CIN
14.298 | 0.267 | tINS | RR | 1 | R37C17[0][B] | g_sound.u_evt_merge/cnt_next_7_s/SUM
14.422 | 0.124 | tNET | RR | 1 | R37C17[3][B] | g_sound.u_evt_merge/n1433_s4/I3
14.869 | 0.448 | tINS | RR | 1 | R37C17[3][B] | g_sound.u_evt_merge/n1433_s4/F
15.011 | 0.142 | tNET | RR | 1 | R37C16[3][A] | g_sound.u_evt_merge/n1433_s3/I2
15.480 | 0.469 | tINS | RR | 1 | R37C16[3][A] | g_sound.u_evt_merge/n1433_s3/F
15.622 | 0.142 | tNET | RR | 1 | R37C15[3][B] | g_sound.u_evt_merge/n1433_s2/I2
16.070 | 0.448 | tINS | RR | 1 | R37C15[3][B] | g_sound.u_evt_merge/n1433_s2/F
16.072 | 0.002 | tNET | RR | 1 | R37C15[2][A] | g_sound.u_evt_merge/n1433_s1/I3
16.546 | 0.474 | tINS | RR | 1 | R37C15[2][A] | g_sound.u_evt_merge/n1433_s1/F
16.858 | 0.313 | tNET | RR | 1 | R37C18[2][B] | g_sound.u_evt_merge/n1433_s0/I3
17.273 | 0.415 | tINS | RR | 38 | R37C18[2][B] | g_sound.u_evt_merge/n1433_s0/F
18.106 | 0.833 | tNET | RR | 1 | R35C6[0][A] | g_sound.u_evt_merge/mem_s3593/I3
18.571 | 0.465 | tINS | RR | 1 | R35C6[0][A] | g_sound.u_evt_merge/mem_s3593/F
18.915 | 0.344 | tNET | RR | 1 | R31C6[1][B] | g_sound.u_evt_merge/mem_s3570/I2
19.379 | 0.465 | tINS | RR | 8 | R31C6[1][B] | g_sound.u_evt_merge/mem_s3570/F
19.832 | 0.452 | tNET | RR | 1 | R31C12[2][A] | g_sound.u_evt_merge/mem_s3546/I2
20.296 | 0.465 | tINS | RR | 70 | R31C12[2][A] | g_sound.u_evt_merge/mem_s3546/F
20.881 | 0.585 | tNET | RR | 1 | R31C8[2][B] | g_sound.u_evt_merge/mem_s3663/I3
21.118 | 0.236 | tINS | RR | 13 | R31C8[2][B] | g_sound.u_evt_merge/mem_s3663/F
21.487 | 0.369 | tNET | RR | 1 | R31C11[2][B] | g_sound.u_evt_merge/mem_s3075/I1
21.960 | 0.474 | tINS | RR | 50 | R31C11[2][B] | g_sound.u_evt_merge/mem_s3075/F
24.113 | 2.153 | tNET | RR | 1 | R35C21[1][A] | g_sound.u_evt_merge/mem_mem_RAMREG_1_G[39]_s0/CE

Data Required Path:

AT | DELAY | TYPE | RF | FANOUT | LOC | NODE
20.000 | 20.000 | | | | | active clock edge time
20.000 | 0.000 | | | | | clk_sys
20.000 | 0.000 | tCL | RR | 1 | IOB117[B] | clk_ibuf/I
21.288 | 1.288 | tINS | RR | 15774 | IOB117[B] | clk_ibuf/O
24.587 | 3.299 | tNET | RR | 1 | R35C21[1][A] | g_sound.u_evt_merge/mem_mem_RAMREG_1_G[39]_s0/CLK
24.307 | -0.280 | tSu | | 1 | R35C21[1][A] | g_sound.u_evt_merge/mem_mem_RAMREG_1_G[39]_s0

Path Statistics:

Clock Skew | 0.008
Setup Relationship | 20.000
Logic Level | 20
Arrival Clock Path Delay | cell: 1.288, 28.136%; route: 3.291, 71.864%
Arrival Data Path Delay | cell: 7.605, 38.932%; route: 11.585, 59.305%; tC2Q: 0.344, 1.762%
Required Clock Path Delay | cell: 1.288, 28.084%; route: 3.299, 71.916%

### Path6

Path Summary:

Slack | 0.222
Data Arrival Time | 24.085
Data Required Time | 24.307
From | g_sound.u_evt_merge/cnt_q_0_s0
To | g_sound.u_evt_merge/mem_mem_RAMREG_4_G[28]_s0
Launch Clk | clk_sys:[R]
Latch Clk | clk_sys:[R]

Data Arrival Path:

AT | DELAY | TYPE | RF | FANOUT | LOC | NODE
0.000 | 0.000 | | | | | active clock edge time
0.000 | 0.000 | | | | | clk_sys
0.000 | 0.000 | tCL | RR | 1 | IOB117[B] | clk_ibuf/I
1.288 | 1.288 | tINS | RR | 15774 | IOB117[B] | clk_ibuf/O
4.579 | 3.291 | tNET | RR | 1 | R37C18[2][A] | g_sound.u_evt_merge/cnt_q_0_s0/CLK
4.923 | 0.344 | tC2Q | RR | 6 | R37C18[2][A] | g_sound.u_evt_merge/cnt_q_0_s0/Q
5.276 | 0.353 | tNET | RR | 1 | R33C18[0][A] | g_sound.u_evt_merge/cnt_after_pop_5_s1/I0
5.750 | 0.474 | tINS | RR | 5 | R33C18[0][A] | g_sound.u_evt_merge/cnt_after_pop_5_s1/F
6.067 | 0.317 | tNET | RR | 1 | R33C16[1][B] | g_sound.u_evt_merge/cnt_after_pop_8_s1/I3
6.541 | 0.474 | tINS | RR | 5 | R33C16[1][B] | g_sound.u_evt_merge/cnt_after_pop_8_s1/F
6.692 | 0.151 | tNET | RR | 1 | R33C17[1][A] | g_sound.u_evt_merge/cnt_after_pop_11_s1/I3
7.107 | 0.415 | tINS | RR | 5 | R33C17[1][A] | g_sound.u_evt_merge/cnt_after_pop_11_s1/F
7.255 | 0.149 | tNET | RR | 1 | R33C18[2][A] | g_sound.u_evt_merge/cnt_after_pop_13_s2/I3
7.670 | 0.415 | tINS | RR | 5 | R33C18[2][A] | g_sound.u_evt_merge/cnt_after_pop_13_s2/F
8.145 | 0.475 | tNET | RR | 1 | R33C15[0][A] | g_sound.u_evt_merge/pop_now_s2/I3
8.381 | 0.236 | tINS | RR | 89 | R33C15[0][A] | g_sound.u_evt_merge/pop_now_s2/F
12.717 | 4.336 | tNET | RR | 1 | R34C16[0][B] | g_sound.u_evt_merge/cnt_after_pop_1_s0/I1
12.953 | 0.236 | tINS | RR | 2 | R34C16[0][B] | g_sound.u_evt_merge/cnt_after_pop_1_s0/F
13.300 | 0.346 | tNET | RR | 2 | R37C16[0][B] | g_sound.u_evt_merge/cnt_next_1_s/I0
13.806 | 0.506 | tINS | RF | 1 | R37C16[0][B] | g_sound.u_evt_merge/cnt_next_1_s/COUT
13.806 | 0.000 | tNET | FF | 2 | R37C16[1][A] | g_sound.u_evt_merge/cnt_next_2_s/CIN
13.851 | 0.045 | tINS | FR | 1 | R37C16[1][A] | g_sound.u_evt_merge/cnt_next_2_s/COUT
13.851 | 0.000 | tNET | RR | 2 | R37C16[1][B] | g_sound.u_evt_merge/cnt_next_3_s/CIN
13.896 | 0.045 | tINS | RR | 1 | R37C16[1][B] | g_sound.u_evt_merge/cnt_next_3_s/COUT
13.896 | 0.000 | tNET | RR | 2 | R37C16[2][A] | g_sound.u_evt_merge/cnt_next_4_s/CIN
13.941 | 0.045 | tINS | RR | 1 | R37C16[2][A] | g_sound.u_evt_merge/cnt_next_4_s/COUT
13.941 | 0.000 | tNET | RR | 2 | R37C16[2][B] | g_sound.u_evt_merge/cnt_next_5_s/CIN
13.986 | 0.045 | tINS | RR | 1 | R37C16[2][B] | g_sound.u_evt_merge/cnt_next_5_s/COUT
13.986 | 0.000 | tNET | RR | 2 | R37C17[0][A] | g_sound.u_evt_merge/cnt_next_6_s/CIN
14.031 | 0.045 | tINS | RR | 1 | R37C17[0][A] | g_sound.u_evt_merge/cnt_next_6_s/COUT
14.031 | 0.000 | tNET | RR | 2 | R37C17[0][B] | g_sound.u_evt_merge/cnt_next_7_s/CIN
14.298 | 0.267 | tINS | RR | 1 | R37C17[0][B] | g_sound.u_evt_merge/cnt_next_7_s/SUM
14.422 | 0.124 | tNET | RR | 1 | R37C17[3][B] | g_sound.u_evt_merge/n1433_s4/I3
14.869 | 0.448 | tINS | RR | 1 | R37C17[3][B] | g_sound.u_evt_merge/n1433_s4/F
15.011 | 0.142 | tNET | RR | 1 | R37C16[3][A] | g_sound.u_evt_merge/n1433_s3/I2
15.480 | 0.469 | tINS | RR | 1 | R37C16[3][A] | g_sound.u_evt_merge/n1433_s3/F
15.622 | 0.142 | tNET | RR | 1 | R37C15[3][B] | g_sound.u_evt_merge/n1433_s2/I2
16.070 | 0.448 | tINS | RR | 1 | R37C15[3][B] | g_sound.u_evt_merge/n1433_s2/F
16.072 | 0.002 | tNET | RR | 1 | R37C15[2][A] | g_sound.u_evt_merge/n1433_s1/I3
16.546 | 0.474 | tINS | RR | 1 | R37C15[2][A] | g_sound.u_evt_merge/n1433_s1/F
16.858 | 0.313 | tNET | RR | 1 | R37C18[2][B] | g_sound.u_evt_merge/n1433_s0/I3
17.273 | 0.415 | tINS | RR | 38 | R37C18[2][B] | g_sound.u_evt_merge/n1433_s0/F
18.106 | 0.833 | tNET | RR | 1 | R35C6[0][A] | g_sound.u_evt_merge/mem_s3593/I3
18.571 | 0.465 | tINS | RR | 1 | R35C6[0][A] | g_sound.u_evt_merge/mem_s3593/F
18.915 | 0.344 | tNET | RR | 1 | R31C6[1][B] | g_sound.u_evt_merge/mem_s3570/I2
19.379 | 0.465 | tINS | RR | 8 | R31C6[1][B] | g_sound.u_evt_merge/mem_s3570/F
19.953 | 0.574 | tNET | RR | 1 | R31C12[3][B] | g_sound.u_evt_merge/mem_s3512/I2
20.401 | 0.448 | tINS | RR | 70 | R31C12[3][B] | g_sound.u_evt_merge/mem_s3512/F
20.896 | 0.495 | tNET | RR | 1 | R31C9[2][B] | g_sound.u_evt_merge/mem_s3662/I3
21.361 | 0.465 | tINS | RR | 13 | R31C9[2][B] | g_sound.u_evt_merge/mem_s3662/F
21.734 | 0.373 | tNET | RR | 1 | R31C12[3][A] | g_sound.u_evt_merge/mem_s3081/I1
22.182 | 0.448 | tINS | RR | 50 | R31C12[3][A] | g_sound.u_evt_merge/mem_s3081/F
24.085 | 1.903 | tNET | RR | 1 | R37C3[1][A] | g_sound.u_evt_merge/mem_mem_RAMREG_4_G[28]_s0/CE

Data Required Path:

AT | DELAY | TYPE | RF | FANOUT | LOC | NODE
20.000 | 20.000 | | | | | active clock edge time
20.000 | 0.000 | | | | | clk_sys
20.000 | 0.000 | tCL | RR | 1 | IOB117[B] | clk_ibuf/I
21.288 | 1.288 | tINS | RR | 15774 | IOB117[B] | clk_ibuf/O
24.587 | 3.299 | tNET | RR | 1 | R37C3[1][A] | g_sound.u_evt_merge/mem_mem_RAMREG_4_G[28]_s0/CLK
24.307 | -0.280 | tSu | | 1 | R37C3[1][A] | g_sound.u_evt_merge/mem_mem_RAMREG_4_G[28]_s0

Path Statistics:

Clock Skew | 0.008
Setup Relationship | 20.000
Logic Level | 20
Arrival Clock Path Delay | cell: 1.288, 28.136%; route: 3.291, 71.864%
Arrival Data Path Delay | cell: 7.791, 39.939%; route: 11.372, 58.296%; tC2Q: 0.344, 1.765%
Required Clock Path Delay | cell: 1.288, 28.084%; route: 3.299, 71.916%

### Path7

Path Summary:

Slack | 0.229
Data Arrival Time | 24.086
Data Required Time | 24.316
From | g_sound.u_evt_merge/cnt_q_0_s0
To | g_sound.u_evt_merge/mem_mem_RAMREG_6_G[21]_s0
Launch Clk | clk_sys:[R]
Latch Clk | clk_sys:[R]

Data Arrival Path:

AT | DELAY | TYPE | RF | FANOUT | LOC | NODE
0.000 | 0.000 | | | | | active clock edge time
0.000 | 0.000 | | | | | clk_sys
0.000 | 0.000 | tCL | RR | 1 | IOB117[B] | clk_ibuf/I
1.288 | 1.288 | tINS | RR | 15774 | IOB117[B] | clk_ibuf/O
4.579 | 3.291 | tNET | RR | 1 | R37C18[2][A] | g_sound.u_evt_merge/cnt_q_0_s0/CLK
4.923 | 0.344 | tC2Q | RR | 6 | R37C18[2][A] | g_sound.u_evt_merge/cnt_q_0_s0/Q
5.276 | 0.353 | tNET | RR | 1 | R33C18[0][A] | g_sound.u_evt_merge/cnt_after_pop_5_s1/I0
5.750 | 0.474 | tINS | RR | 5 | R33C18[0][A] | g_sound.u_evt_merge/cnt_after_pop_5_s1/F
6.067 | 0.317 | tNET | RR | 1 | R33C16[1][B] | g_sound.u_evt_merge/cnt_after_pop_8_s1/I3
6.541 | 0.474 | tINS | RR | 5 | R33C16[1][B] | g_sound.u_evt_merge/cnt_after_pop_8_s1/F
6.692 | 0.151 | tNET | RR | 1 | R33C17[1][A] | g_sound.u_evt_merge/cnt_after_pop_11_s1/I3
7.107 | 0.415 | tINS | RR | 5 | R33C17[1][A] | g_sound.u_evt_merge/cnt_after_pop_11_s1/F
7.255 | 0.149 | tNET | RR | 1 | R33C18[2][A] | g_sound.u_evt_merge/cnt_after_pop_13_s2/I3
7.670 | 0.415 | tINS | RR | 5 | R33C18[2][A] | g_sound.u_evt_merge/cnt_after_pop_13_s2/F
8.145 | 0.475 | tNET | RR | 1 | R33C15[0][A] | g_sound.u_evt_merge/pop_now_s2/I3
8.381 | 0.236 | tINS | RR | 89 | R33C15[0][A] | g_sound.u_evt_merge/pop_now_s2/F
12.717 | 4.336 | tNET | RR | 1 | R34C16[0][B] | g_sound.u_evt_merge/cnt_after_pop_1_s0/I1
12.953 | 0.236 | tINS | RR | 2 | R34C16[0][B] | g_sound.u_evt_merge/cnt_after_pop_1_s0/F
13.300 | 0.346 | tNET | RR | 2 | R37C16[0][B] | g_sound.u_evt_merge/cnt_next_1_s/I0
13.806 | 0.506 | tINS | RF | 1 | R37C16[0][B] | g_sound.u_evt_merge/cnt_next_1_s/COUT
13.806 | 0.000 | tNET | FF | 2 | R37C16[1][A] | g_sound.u_evt_merge/cnt_next_2_s/CIN
13.851 | 0.045 | tINS | FR | 1 | R37C16[1][A] | g_sound.u_evt_merge/cnt_next_2_s/COUT
13.851 | 0.000 | tNET | RR | 2 | R37C16[1][B] | g_sound.u_evt_merge/cnt_next_3_s/CIN
13.896 | 0.045 | tINS | RR | 1 | R37C16[1][B] | g_sound.u_evt_merge/cnt_next_3_s/COUT
13.896 | 0.000 | tNET | RR | 2 | R37C16[2][A] | g_sound.u_evt_merge/cnt_next_4_s/CIN
13.941 | 0.045 | tINS | RR | 1 | R37C16[2][A] | g_sound.u_evt_merge/cnt_next_4_s/COUT
13.941 | 0.000 | tNET | RR | 2 | R37C16[2][B] | g_sound.u_evt_merge/cnt_next_5_s/CIN
13.986 | 0.045 | tINS | RR | 1 | R37C16[2][B] | g_sound.u_evt_merge/cnt_next_5_s/COUT
13.986 | 0.000 | tNET | RR | 2 | R37C17[0][A] | g_sound.u_evt_merge/cnt_next_6_s/CIN
14.031 | 0.045 | tINS | RR | 1 | R37C17[0][A] | g_sound.u_evt_merge/cnt_next_6_s/COUT
14.031 | 0.000 | tNET | RR | 2 | R37C17[0][B] | g_sound.u_evt_merge/cnt_next_7_s/CIN
14.298 | 0.267 | tINS | RR | 1 | R37C17[0][B] | g_sound.u_evt_merge/cnt_next_7_s/SUM
14.422 | 0.124 | tNET | RR | 1 | R37C17[3][B] | g_sound.u_evt_merge/n1433_s4/I3
14.869 | 0.448 | tINS | RR | 1 | R37C17[3][B] | g_sound.u_evt_merge/n1433_s4/F
15.011 | 0.142 | tNET | RR | 1 | R37C16[3][A] | g_sound.u_evt_merge/n1433_s3/I2
15.480 | 0.469 | tINS | RR | 1 | R37C16[3][A] | g_sound.u_evt_merge/n1433_s3/F
15.622 | 0.142 | tNET | RR | 1 | R37C15[3][B] | g_sound.u_evt_merge/n1433_s2/I2
16.070 | 0.448 | tINS | RR | 1 | R37C15[3][B] | g_sound.u_evt_merge/n1433_s2/F
16.072 | 0.002 | tNET | RR | 1 | R37C15[2][A] | g_sound.u_evt_merge/n1433_s1/I3
16.546 | 0.474 | tINS | RR | 1 | R37C15[2][A] | g_sound.u_evt_merge/n1433_s1/F
16.858 | 0.313 | tNET | RR | 1 | R37C18[2][B] | g_sound.u_evt_merge/n1433_s0/I3
17.273 | 0.415 | tINS | RR | 38 | R37C18[2][B] | g_sound.u_evt_merge/n1433_s0/F
18.954 | 1.681 | tNET | RR | 1 | R35C5[3][B] | g_sound.u_evt_merge/mem_s3632/I2
19.423 | 0.469 | tINS | RR | 4 | R35C5[3][B] | g_sound.u_evt_merge/mem_s3632/F
19.428 | 0.005 | tNET | RR | 1 | R35C5[0][B] | g_sound.u_evt_merge/mem_s3641/I3
19.901 | 0.474 | tINS | RR | 51 | R35C5[0][B] | g_sound.u_evt_merge/mem_s3641/F
21.393 | 1.492 | tNET | RR | 1 | R33C13[0][A] | g_sound.u_evt_merge/mem_s3085/I0
21.629 | 0.236 | tINS | RR | 50 | R33C13[0][A] | g_sound.u_evt_merge/mem_s3085/F
24.086 | 2.457 | tNET | RR | 1 | R31C24[0][A] | g_sound.u_evt_merge/mem_mem_RAMREG_6_G[21]_s0/CE

Data Required Path:

AT | DELAY | TYPE | RF | FANOUT | LOC | NODE
20.000 | 20.000 | | | | | active clock edge time
20.000 | 0.000 | | | | | clk_sys
20.000 | 0.000 | tCL | RR | 1 | IOB117[B] | clk_ibuf/I
21.288 | 1.288 | tINS | RR | 15774 | IOB117[B] | clk_ibuf/O
24.596 | 3.307 | tNET | RR | 1 | R31C24[0][A] | g_sound.u_evt_merge/mem_mem_RAMREG_6_G[21]_s0/CLK
24.316 | -0.280 | tSu | | 1 | R31C24[0][A] | g_sound.u_evt_merge/mem_mem_RAMREG_6_G[21]_s0

Path Statistics:

Clock Skew | 0.017
Setup Relationship | 20.000
Logic Level | 18
Arrival Clock Path Delay | cell: 1.288, 28.136%; route: 3.291, 71.864%
Arrival Data Path Delay | cell: 6.680, 34.245%; route: 12.483, 63.991%; tC2Q: 0.344, 1.765%
Required Clock Path Delay | cell: 1.288, 28.033%; route: 3.307, 71.967%

### Path8

Path Summary:

Slack | 0.324
Data Arrival Time | 23.992
Data Required Time | 24.316
From | g_sound.u_evt_merge/cnt_q_0_s0
To | g_sound.u_evt_merge/mem_mem_RAMREG_1_G[20]_s0
Launch Clk | clk_sys:[R]
Latch Clk | clk_sys:[R]

Data Arrival Path:

AT | DELAY | TYPE | RF | FANOUT | LOC | NODE
0.000 | 0.000 | | | | | active clock edge time
0.000 | 0.000 | | | | | clk_sys
0.000 | 0.000 | tCL | RR | 1 | IOB117[B] | clk_ibuf/I
1.288 | 1.288 | tINS | RR | 15774 | IOB117[B] | clk_ibuf/O
4.579 | 3.291 | tNET | RR | 1 | R37C18[2][A] | g_sound.u_evt_merge/cnt_q_0_s0/CLK
4.923 | 0.344 | tC2Q | RR | 6 | R37C18[2][A] | g_sound.u_evt_merge/cnt_q_0_s0/Q
5.276 | 0.353 | tNET | RR | 1 | R33C18[0][A] | g_sound.u_evt_merge/cnt_after_pop_5_s1/I0
5.750 | 0.474 | tINS | RR | 5 | R33C18[0][A] | g_sound.u_evt_merge/cnt_after_pop_5_s1/F
6.067 | 0.317 | tNET | RR | 1 | R33C16[1][B] | g_sound.u_evt_merge/cnt_after_pop_8_s1/I3
6.541 | 0.474 | tINS | RR | 5 | R33C16[1][B] | g_sound.u_evt_merge/cnt_after_pop_8_s1/F
6.692 | 0.151 | tNET | RR | 1 | R33C17[1][A] | g_sound.u_evt_merge/cnt_after_pop_11_s1/I3
7.107 | 0.415 | tINS | RR | 5 | R33C17[1][A] | g_sound.u_evt_merge/cnt_after_pop_11_s1/F
7.255 | 0.149 | tNET | RR | 1 | R33C18[2][A] | g_sound.u_evt_merge/cnt_after_pop_13_s2/I3
7.670 | 0.415 | tINS | RR | 5 | R33C18[2][A] | g_sound.u_evt_merge/cnt_after_pop_13_s2/F
8.145 | 0.475 | tNET | RR | 1 | R33C15[0][A] | g_sound.u_evt_merge/pop_now_s2/I3
8.381 | 0.236 | tINS | RR | 89 | R33C15[0][A] | g_sound.u_evt_merge/pop_now_s2/F
12.717 | 4.336 | tNET | RR | 1 | R34C16[0][B] | g_sound.u_evt_merge/cnt_after_pop_1_s0/I1
12.953 | 0.236 | tINS | RR | 2 | R34C16[0][B] | g_sound.u_evt_merge/cnt_after_pop_1_s0/F
13.300 | 0.346 | tNET | RR | 2 | R37C16[0][B] | g_sound.u_evt_merge/cnt_next_1_s/I0
13.806 | 0.506 | tINS | RF | 1 | R37C16[0][B] | g_sound.u_evt_merge/cnt_next_1_s/COUT
13.806 | 0.000 | tNET | FF | 2 | R37C16[1][A] | g_sound.u_evt_merge/cnt_next_2_s/CIN
13.851 | 0.045 | tINS | FR | 1 | R37C16[1][A] | g_sound.u_evt_merge/cnt_next_2_s/COUT
13.851 | 0.000 | tNET | RR | 2 | R37C16[1][B] | g_sound.u_evt_merge/cnt_next_3_s/CIN
13.896 | 0.045 | tINS | RR | 1 | R37C16[1][B] | g_sound.u_evt_merge/cnt_next_3_s/COUT
13.896 | 0.000 | tNET | RR | 2 | R37C16[2][A] | g_sound.u_evt_merge/cnt_next_4_s/CIN
13.941 | 0.045 | tINS | RR | 1 | R37C16[2][A] | g_sound.u_evt_merge/cnt_next_4_s/COUT
13.941 | 0.000 | tNET | RR | 2 | R37C16[2][B] | g_sound.u_evt_merge/cnt_next_5_s/CIN
13.986 | 0.045 | tINS | RR | 1 | R37C16[2][B] | g_sound.u_evt_merge/cnt_next_5_s/COUT
13.986 | 0.000 | tNET | RR | 2 | R37C17[0][A] | g_sound.u_evt_merge/cnt_next_6_s/CIN
14.031 | 0.045 | tINS | RR | 1 | R37C17[0][A] | g_sound.u_evt_merge/cnt_next_6_s/COUT
14.031 | 0.000 | tNET | RR | 2 | R37C17[0][B] | g_sound.u_evt_merge/cnt_next_7_s/CIN
14.298 | 0.267 | tINS | RR | 1 | R37C17[0][B] | g_sound.u_evt_merge/cnt_next_7_s/SUM
14.422 | 0.124 | tNET | RR | 1 | R37C17[3][B] | g_sound.u_evt_merge/n1433_s4/I3
14.869 | 0.448 | tINS | RR | 1 | R37C17[3][B] | g_sound.u_evt_merge/n1433_s4/F
15.011 | 0.142 | tNET | RR | 1 | R37C16[3][A] | g_sound.u_evt_merge/n1433_s3/I2
15.480 | 0.469 | tINS | RR | 1 | R37C16[3][A] | g_sound.u_evt_merge/n1433_s3/F
15.622 | 0.142 | tNET | RR | 1 | R37C15[3][B] | g_sound.u_evt_merge/n1433_s2/I2
16.070 | 0.448 | tINS | RR | 1 | R37C15[3][B] | g_sound.u_evt_merge/n1433_s2/F
16.072 | 0.002 | tNET | RR | 1 | R37C15[2][A] | g_sound.u_evt_merge/n1433_s1/I3
16.546 | 0.474 | tINS | RR | 1 | R37C15[2][A] | g_sound.u_evt_merge/n1433_s1/F
16.858 | 0.313 | tNET | RR | 1 | R37C18[2][B] | g_sound.u_evt_merge/n1433_s0/I3
17.273 | 0.415 | tINS | RR | 38 | R37C18[2][B] | g_sound.u_evt_merge/n1433_s0/F
18.106 | 0.833 | tNET | RR | 1 | R35C6[0][A] | g_sound.u_evt_merge/mem_s3593/I3
18.571 | 0.465 | tINS | RR | 1 | R35C6[0][A] | g_sound.u_evt_merge/mem_s3593/F
18.915 | 0.344 | tNET | RR | 1 | R31C6[1][B] | g_sound.u_evt_merge/mem_s3570/I2
19.379 | 0.465 | tINS | RR | 8 | R31C6[1][B] | g_sound.u_evt_merge/mem_s3570/F
19.832 | 0.452 | tNET | RR | 1 | R31C12[2][A] | g_sound.u_evt_merge/mem_s3546/I2
20.296 | 0.465 | tINS | RR | 70 | R31C12[2][A] | g_sound.u_evt_merge/mem_s3546/F
20.881 | 0.585 | tNET | RR | 1 | R31C8[2][B] | g_sound.u_evt_merge/mem_s3663/I3
21.118 | 0.236 | tINS | RR | 13 | R31C8[2][B] | g_sound.u_evt_merge/mem_s3663/F
21.487 | 0.369 | tNET | RR | 1 | R31C11[2][B] | g_sound.u_evt_merge/mem_s3075/I1
21.960 | 0.474 | tINS | RR | 50 | R31C11[2][B] | g_sound.u_evt_merge/mem_s3075/F
23.992 | 2.032 | tNET | RR | 1 | R36C20[1][A] | g_sound.u_evt_merge/mem_mem_RAMREG_1_G[20]_s0/CE

Data Required Path:

AT | DELAY | TYPE | RF | FANOUT | LOC | NODE
20.000 | 20.000 | | | | | active clock edge time
20.000 | 0.000 | | | | | clk_sys
20.000 | 0.000 | tCL | RR | 1 | IOB117[B] | clk_ibuf/I
21.288 | 1.288 | tINS | RR | 15774 | IOB117[B] | clk_ibuf/O
24.596 | 3.307 | tNET | RR | 1 | R36C20[1][A] | g_sound.u_evt_merge/mem_mem_RAMREG_1_G[20]_s0/CLK
24.316 | -0.280 | tSu | | 1 | R36C20[1][A] | g_sound.u_evt_merge/mem_mem_RAMREG_1_G[20]_s0

Path Statistics:

Clock Skew | 0.017
Setup Relationship | 20.000
Logic Level | 20
Arrival Clock Path Delay | cell: 1.288, 28.136%; route: 3.291, 71.864%
Arrival Data Path Delay | cell: 7.605, 39.175%; route: 11.464, 59.052%; tC2Q: 0.344, 1.773%
Required Clock Path Delay | cell: 1.288, 28.033%; route: 3.307, 71.967%

### Path9

Path Summary:

Slack | 0.378
Data Arrival Time | 23.921
Data Required Time | 24.299
From | g_sound.u_evt_merge/cnt_q_0_s0
To | g_sound.u_evt_merge/mem_mem_RAMREG_6_G[28]_s0
Launch Clk | clk_sys:[R]
Latch Clk | clk_sys:[R]

Data Arrival Path:

AT | DELAY | TYPE | RF | FANOUT | LOC | NODE
0.000 | 0.000 | | | | | active clock edge time
0.000 | 0.000 | | | | | clk_sys
0.000 | 0.000 | tCL | RR | 1 | IOB117[B] | clk_ibuf/I
1.288 | 1.288 | tINS | RR | 15774 | IOB117[B] | clk_ibuf/O
4.579 | 3.291 | tNET | RR | 1 | R37C18[2][A] | g_sound.u_evt_merge/cnt_q_0_s0/CLK
4.923 | 0.344 | tC2Q | RR | 6 | R37C18[2][A] | g_sound.u_evt_merge/cnt_q_0_s0/Q
5.276 | 0.353 | tNET | RR | 1 | R33C18[0][A] | g_sound.u_evt_merge/cnt_after_pop_5_s1/I0
5.750 | 0.474 | tINS | RR | 5 | R33C18[0][A] | g_sound.u_evt_merge/cnt_after_pop_5_s1/F
6.067 | 0.317 | tNET | RR | 1 | R33C16[1][B] | g_sound.u_evt_merge/cnt_after_pop_8_s1/I3
6.541 | 0.474 | tINS | RR | 5 | R33C16[1][B] | g_sound.u_evt_merge/cnt_after_pop_8_s1/F
6.692 | 0.151 | tNET | RR | 1 | R33C17[1][A] | g_sound.u_evt_merge/cnt_after_pop_11_s1/I3
7.107 | 0.415 | tINS | RR | 5 | R33C17[1][A] | g_sound.u_evt_merge/cnt_after_pop_11_s1/F
7.255 | 0.149 | tNET | RR | 1 | R33C18[2][A] | g_sound.u_evt_merge/cnt_after_pop_13_s2/I3
7.670 | 0.415 | tINS | RR | 5 | R33C18[2][A] | g_sound.u_evt_merge/cnt_after_pop_13_s2/F
8.145 | 0.475 | tNET | RR | 1 | R33C15[0][A] | g_sound.u_evt_merge/pop_now_s2/I3
8.381 | 0.236 | tINS | RR | 89 | R33C15[0][A] | g_sound.u_evt_merge/pop_now_s2/F
12.717 | 4.336 | tNET | RR | 1 | R34C16[0][B] | g_sound.u_evt_merge/cnt_after_pop_1_s0/I1
12.953 | 0.236 | tINS | RR | 2 | R34C16[0][B] | g_sound.u_evt_merge/cnt_after_pop_1_s0/F
13.300 | 0.346 | tNET | RR | 2 | R37C16[0][B] | g_sound.u_evt_merge/cnt_next_1_s/I0
13.806 | 0.506 | tINS | RF | 1 | R37C16[0][B] | g_sound.u_evt_merge/cnt_next_1_s/COUT
13.806 | 0.000 | tNET | FF | 2 | R37C16[1][A] | g_sound.u_evt_merge/cnt_next_2_s/CIN
13.851 | 0.045 | tINS | FR | 1 | R37C16[1][A] | g_sound.u_evt_merge/cnt_next_2_s/COUT
13.851 | 0.000 | tNET | RR | 2 | R37C16[1][B] | g_sound.u_evt_merge/cnt_next_3_s/CIN
13.896 | 0.045 | tINS | RR | 1 | R37C16[1][B] | g_sound.u_evt_merge/cnt_next_3_s/COUT
13.896 | 0.000 | tNET | RR | 2 | R37C16[2][A] | g_sound.u_evt_merge/cnt_next_4_s/CIN
13.941 | 0.045 | tINS | RR | 1 | R37C16[2][A] | g_sound.u_evt_merge/cnt_next_4_s/COUT
13.941 | 0.000 | tNET | RR | 2 | R37C16[2][B] | g_sound.u_evt_merge/cnt_next_5_s/CIN
13.986 | 0.045 | tINS | RR | 1 | R37C16[2][B] | g_sound.u_evt_merge/cnt_next_5_s/COUT
13.986 | 0.000 | tNET | RR | 2 | R37C17[0][A] | g_sound.u_evt_merge/cnt_next_6_s/CIN
14.031 | 0.045 | tINS | RR | 1 | R37C17[0][A] | g_sound.u_evt_merge/cnt_next_6_s/COUT
14.031 | 0.000 | tNET | RR | 2 | R37C17[0][B] | g_sound.u_evt_merge/cnt_next_7_s/CIN
14.298 | 0.267 | tINS | RR | 1 | R37C17[0][B] | g_sound.u_evt_merge/cnt_next_7_s/SUM
14.422 | 0.124 | tNET | RR | 1 | R37C17[3][B] | g_sound.u_evt_merge/n1433_s4/I3
14.869 | 0.448 | tINS | RR | 1 | R37C17[3][B] | g_sound.u_evt_merge/n1433_s4/F
15.011 | 0.142 | tNET | RR | 1 | R37C16[3][A] | g_sound.u_evt_merge/n1433_s3/I2
15.480 | 0.469 | tINS | RR | 1 | R37C16[3][A] | g_sound.u_evt_merge/n1433_s3/F
15.622 | 0.142 | tNET | RR | 1 | R37C15[3][B] | g_sound.u_evt_merge/n1433_s2/I2
16.070 | 0.448 | tINS | RR | 1 | R37C15[3][B] | g_sound.u_evt_merge/n1433_s2/F
16.072 | 0.002 | tNET | RR | 1 | R37C15[2][A] | g_sound.u_evt_merge/n1433_s1/I3
16.546 | 0.474 | tINS | RR | 1 | R37C15[2][A] | g_sound.u_evt_merge/n1433_s1/F
16.858 | 0.313 | tNET | RR | 1 | R37C18[2][B] | g_sound.u_evt_merge/n1433_s0/I3
17.273 | 0.415 | tINS | RR | 38 | R37C18[2][B] | g_sound.u_evt_merge/n1433_s0/F
18.954 | 1.681 | tNET | RR | 1 | R35C5[3][B] | g_sound.u_evt_merge/mem_s3632/I2
19.423 | 0.469 | tINS | RR | 4 | R35C5[3][B] | g_sound.u_evt_merge/mem_s3632/F
19.428 | 0.005 | tNET | RR | 1 | R35C5[0][B] | g_sound.u_evt_merge/mem_s3641/I3
19.901 | 0.474 | tINS | RR | 51 | R35C5[0][B] | g_sound.u_evt_merge/mem_s3641/F
21.393 | 1.492 | tNET | RR | 1 | R33C13[0][A] | g_sound.u_evt_merge/mem_s3085/I0
21.629 | 0.236 | tINS | RR | 50 | R33C13[0][A] | g_sound.u_evt_merge/mem_s3085/F
23.921 | 2.292 | tNET | RR | 1 | R37C2[0][B] | g_sound.u_evt_merge/mem_mem_RAMREG_6_G[28]_s0/CE

Data Required Path:

AT | DELAY | TYPE | RF | FANOUT | LOC | NODE
20.000 | 20.000 | | | | | active clock edge time
20.000 | 0.000 | | | | | clk_sys
20.000 | 0.000 | tCL | RR | 1 | IOB117[B] | clk_ibuf/I
21.288 | 1.288 | tINS | RR | 15774 | IOB117[B] | clk_ibuf/O
24.579 | 3.291 | tNET | RR | 1 | R37C2[0][B] | g_sound.u_evt_merge/mem_mem_RAMREG_6_G[28]_s0/CLK
24.299 | -0.280 | tSu | | 1 | R37C2[0][B] | g_sound.u_evt_merge/mem_mem_RAMREG_6_G[28]_s0

Path Statistics:

Clock Skew | 0.000
Setup Relationship | 20.000
Logic Level | 18
Arrival Clock Path Delay | cell: 1.288, 28.136%; route: 3.291, 71.864%
Arrival Data Path Delay | cell: 6.680, 34.537%; route: 12.318, 63.683%; tC2Q: 0.344, 1.780%
Required Clock Path Delay | cell: 1.288, 28.136%; route: 3.291, 71.864%

### Path10

Path Summary:

Slack | 0.378
Data Arrival Time | 23.921
Data Required Time | 24.299
From | g_sound.u_evt_merge/cnt_q_0_s0
To | g_sound.u_evt_merge/mem_mem_RAMREG_6_G[25]_s0
Launch Clk | clk_sys:[R]
Latch Clk | clk_sys:[R]

Data Arrival Path:

AT | DELAY | TYPE | RF | FANOUT | LOC | NODE
0.000 | 0.000 | | | | | active clock edge time
0.000 | 0.000 | | | | | clk_sys
0.000 | 0.000 | tCL | RR | 1 | IOB117[B] | clk_ibuf/I
1.288 | 1.288 | tINS | RR | 15774 | IOB117[B] | clk_ibuf/O
4.579 | 3.291 | tNET | RR | 1 | R37C18[2][A] | g_sound.u_evt_merge/cnt_q_0_s0/CLK
4.923 | 0.344 | tC2Q | RR | 6 | R37C18[2][A] | g_sound.u_evt_merge/cnt_q_0_s0/Q
5.276 | 0.353 | tNET | RR | 1 | R33C18[0][A] | g_sound.u_evt_merge/cnt_after_pop_5_s1/I0
5.750 | 0.474 | tINS | RR | 5 | R33C18[0][A] | g_sound.u_evt_merge/cnt_after_pop_5_s1/F
6.067 | 0.317 | tNET | RR | 1 | R33C16[1][B] | g_sound.u_evt_merge/cnt_after_pop_8_s1/I3
6.541 | 0.474 | tINS | RR | 5 | R33C16[1][B] | g_sound.u_evt_merge/cnt_after_pop_8_s1/F
6.692 | 0.151 | tNET | RR | 1 | R33C17[1][A] | g_sound.u_evt_merge/cnt_after_pop_11_s1/I3
7.107 | 0.415 | tINS | RR | 5 | R33C17[1][A] | g_sound.u_evt_merge/cnt_after_pop_11_s1/F
7.255 | 0.149 | tNET | RR | 1 | R33C18[2][A] | g_sound.u_evt_merge/cnt_after_pop_13_s2/I3
7.670 | 0.415 | tINS | RR | 5 | R33C18[2][A] | g_sound.u_evt_merge/cnt_after_pop_13_s2/F
8.145 | 0.475 | tNET | RR | 1 | R33C15[0][A] | g_sound.u_evt_merge/pop_now_s2/I3
8.381 | 0.236 | tINS | RR | 89 | R33C15[0][A] | g_sound.u_evt_merge/pop_now_s2/F
12.717 | 4.336 | tNET | RR | 1 | R34C16[0][B] | g_sound.u_evt_merge/cnt_after_pop_1_s0/I1
12.953 | 0.236 | tINS | RR | 2 | R34C16[0][B] | g_sound.u_evt_merge/cnt_after_pop_1_s0/F
13.300 | 0.346 | tNET | RR | 2 | R37C16[0][B] | g_sound.u_evt_merge/cnt_next_1_s/I0
13.806 | 0.506 | tINS | RF | 1 | R37C16[0][B] | g_sound.u_evt_merge/cnt_next_1_s/COUT
13.806 | 0.000 | tNET | FF | 2 | R37C16[1][A] | g_sound.u_evt_merge/cnt_next_2_s/CIN
13.851 | 0.045 | tINS | FR | 1 | R37C16[1][A] | g_sound.u_evt_merge/cnt_next_2_s/COUT
13.851 | 0.000 | tNET | RR | 2 | R37C16[1][B] | g_sound.u_evt_merge/cnt_next_3_s/CIN
13.896 | 0.045 | tINS | RR | 1 | R37C16[1][B] | g_sound.u_evt_merge/cnt_next_3_s/COUT
13.896 | 0.000 | tNET | RR | 2 | R37C16[2][A] | g_sound.u_evt_merge/cnt_next_4_s/CIN
13.941 | 0.045 | tINS | RR | 1 | R37C16[2][A] | g_sound.u_evt_merge/cnt_next_4_s/COUT
13.941 | 0.000 | tNET | RR | 2 | R37C16[2][B] | g_sound.u_evt_merge/cnt_next_5_s/CIN
13.986 | 0.045 | tINS | RR | 1 | R37C16[2][B] | g_sound.u_evt_merge/cnt_next_5_s/COUT
13.986 | 0.000 | tNET | RR | 2 | R37C17[0][A] | g_sound.u_evt_merge/cnt_next_6_s/CIN
14.031 | 0.045 | tINS | RR | 1 | R37C17[0][A] | g_sound.u_evt_merge/cnt_next_6_s/COUT
14.031 | 0.000 | tNET | RR | 2 | R37C17[0][B] | g_sound.u_evt_merge/cnt_next_7_s/CIN
14.298 | 0.267 | tINS | RR | 1 | R37C17[0][B] | g_sound.u_evt_merge/cnt_next_7_s/SUM
14.422 | 0.124 | tNET | RR | 1 | R37C17[3][B] | g_sound.u_evt_merge/n1433_s4/I3
14.869 | 0.448 | tINS | RR | 1 | R37C17[3][B] | g_sound.u_evt_merge/n1433_s4/F
15.011 | 0.142 | tNET | RR | 1 | R37C16[3][A] | g_sound.u_evt_merge/n1433_s3/I2
15.480 | 0.469 | tINS | RR | 1 | R37C16[3][A] | g_sound.u_evt_merge/n1433_s3/F
15.622 | 0.142 | tNET | RR | 1 | R37C15[3][B] | g_sound.u_evt_merge/n1433_s2/I2
16.070 | 0.448 | tINS | RR | 1 | R37C15[3][B] | g_sound.u_evt_merge/n1433_s2/F
16.072 | 0.002 | tNET | RR | 1 | R37C15[2][A] | g_sound.u_evt_merge/n1433_s1/I3
16.546 | 0.474 | tINS | RR | 1 | R37C15[2][A] | g_sound.u_evt_merge/n1433_s1/F
16.858 | 0.313 | tNET | RR | 1 | R37C18[2][B] | g_sound.u_evt_merge/n1433_s0/I3
17.273 | 0.415 | tINS | RR | 38 | R37C18[2][B] | g_sound.u_evt_merge/n1433_s0/F
18.954 | 1.681 | tNET | RR | 1 | R35C5[3][B] | g_sound.u_evt_merge/mem_s3632/I2
19.423 | 0.469 | tINS | RR | 4 | R35C5[3][B] | g_sound.u_evt_merge/mem_s3632/F
19.428 | 0.005 | tNET | RR | 1 | R35C5[0][B] | g_sound.u_evt_merge/mem_s3641/I3
19.901 | 0.474 | tINS | RR | 51 | R35C5[0][B] | g_sound.u_evt_merge/mem_s3641/F
21.393 | 1.492 | tNET | RR | 1 | R33C13[0][A] | g_sound.u_evt_merge/mem_s3085/I0
21.629 | 0.236 | tINS | RR | 50 | R33C13[0][A] | g_sound.u_evt_merge/mem_s3085/F
23.921 | 2.292 | tNET | RR | 1 | R37C2[2][A] | g_sound.u_evt_merge/mem_mem_RAMREG_6_G[25]_s0/CE

Data Required Path:

AT | DELAY | TYPE | RF | FANOUT | LOC | NODE
20.000 | 20.000 | | | | | active clock edge time
20.000 | 0.000 | | | | | clk_sys
20.000 | 0.000 | tCL | RR | 1 | IOB117[B] | clk_ibuf/I
21.288 | 1.288 | tINS | RR | 15774 | IOB117[B] | clk_ibuf/O
24.579 | 3.291 | tNET | RR | 1 | R37C2[2][A] | g_sound.u_evt_merge/mem_mem_RAMREG_6_G[25]_s0/CLK
24.299 | -0.280 | tSu | | 1 | R37C2[2][A] | g_sound.u_evt_merge/mem_mem_RAMREG_6_G[25]_s0

Path Statistics:

Clock Skew | 0.000
Setup Relationship | 20.000
Logic Level | 18
Arrival Clock Path Delay | cell: 1.288, 28.136%; route: 3.291, 71.864%
Arrival Data Path Delay | cell: 6.680, 34.537%; route: 12.318, 63.683%; tC2Q: 0.344, 1.780%
Required Clock Path Delay | cell: 1.288, 28.136%; route: 3.291, 71.864%

### Path11

Path Summary:

Slack | 0.378
Data Arrival Time | 23.937
Data Required Time | 24.316
From | g_sound.u_evt_merge/cnt_q_0_s0
To | g_sound.u_evt_merge/mem_mem_RAMREG_1_G[29]_s0
Launch Clk | clk_sys:[R]
Latch Clk | clk_sys:[R]

Data Arrival Path:

AT | DELAY | TYPE | RF | FANOUT | LOC | NODE
0.000 | 0.000 | | | | | active clock edge time
0.000 | 0.000 | | | | | clk_sys
0.000 | 0.000 | tCL | RR | 1 | IOB117[B] | clk_ibuf/I
1.288 | 1.288 | tINS | RR | 15774 | IOB117[B] | clk_ibuf/O
4.579 | 3.291 | tNET | RR | 1 | R37C18[2][A] | g_sound.u_evt_merge/cnt_q_0_s0/CLK
4.923 | 0.344 | tC2Q | RR | 6 | R37C18[2][A] | g_sound.u_evt_merge/cnt_q_0_s0/Q
5.276 | 0.353 | tNET | RR | 1 | R33C18[0][A] | g_sound.u_evt_merge/cnt_after_pop_5_s1/I0
5.750 | 0.474 | tINS | RR | 5 | R33C18[0][A] | g_sound.u_evt_merge/cnt_after_pop_5_s1/F
6.067 | 0.317 | tNET | RR | 1 | R33C16[1][B] | g_sound.u_evt_merge/cnt_after_pop_8_s1/I3
6.541 | 0.474 | tINS | RR | 5 | R33C16[1][B] | g_sound.u_evt_merge/cnt_after_pop_8_s1/F
6.692 | 0.151 | tNET | RR | 1 | R33C17[1][A] | g_sound.u_evt_merge/cnt_after_pop_11_s1/I3
7.107 | 0.415 | tINS | RR | 5 | R33C17[1][A] | g_sound.u_evt_merge/cnt_after_pop_11_s1/F
7.255 | 0.149 | tNET | RR | 1 | R33C18[2][A] | g_sound.u_evt_merge/cnt_after_pop_13_s2/I3
7.670 | 0.415 | tINS | RR | 5 | R33C18[2][A] | g_sound.u_evt_merge/cnt_after_pop_13_s2/F
8.145 | 0.475 | tNET | RR | 1 | R33C15[0][A] | g_sound.u_evt_merge/pop_now_s2/I3
8.381 | 0.236 | tINS | RR | 89 | R33C15[0][A] | g_sound.u_evt_merge/pop_now_s2/F
12.717 | 4.336 | tNET | RR | 1 | R34C16[0][B] | g_sound.u_evt_merge/cnt_after_pop_1_s0/I1
12.953 | 0.236 | tINS | RR | 2 | R34C16[0][B] | g_sound.u_evt_merge/cnt_after_pop_1_s0/F
13.300 | 0.346 | tNET | RR | 2 | R37C16[0][B] | g_sound.u_evt_merge/cnt_next_1_s/I0
13.806 | 0.506 | tINS | RF | 1 | R37C16[0][B] | g_sound.u_evt_merge/cnt_next_1_s/COUT
13.806 | 0.000 | tNET | FF | 2 | R37C16[1][A] | g_sound.u_evt_merge/cnt_next_2_s/CIN
13.851 | 0.045 | tINS | FR | 1 | R37C16[1][A] | g_sound.u_evt_merge/cnt_next_2_s/COUT
13.851 | 0.000 | tNET | RR | 2 | R37C16[1][B] | g_sound.u_evt_merge/cnt_next_3_s/CIN
13.896 | 0.045 | tINS | RR | 1 | R37C16[1][B] | g_sound.u_evt_merge/cnt_next_3_s/COUT
13.896 | 0.000 | tNET | RR | 2 | R37C16[2][A] | g_sound.u_evt_merge/cnt_next_4_s/CIN
13.941 | 0.045 | tINS | RR | 1 | R37C16[2][A] | g_sound.u_evt_merge/cnt_next_4_s/COUT
13.941 | 0.000 | tNET | RR | 2 | R37C16[2][B] | g_sound.u_evt_merge/cnt_next_5_s/CIN
13.986 | 0.045 | tINS | RR | 1 | R37C16[2][B] | g_sound.u_evt_merge/cnt_next_5_s/COUT
13.986 | 0.000 | tNET | RR | 2 | R37C17[0][A] | g_sound.u_evt_merge/cnt_next_6_s/CIN
14.031 | 0.045 | tINS | RR | 1 | R37C17[0][A] | g_sound.u_evt_merge/cnt_next_6_s/COUT
14.031 | 0.000 | tNET | RR | 2 | R37C17[0][B] | g_sound.u_evt_merge/cnt_next_7_s/CIN
14.298 | 0.267 | tINS | RR | 1 | R37C17[0][B] | g_sound.u_evt_merge/cnt_next_7_s/SUM
14.422 | 0.124 | tNET | RR | 1 | R37C17[3][B] | g_sound.u_evt_merge/n1433_s4/I3
14.869 | 0.448 | tINS | RR | 1 | R37C17[3][B] | g_sound.u_evt_merge/n1433_s4/F
15.011 | 0.142 | tNET | RR | 1 | R37C16[3][A] | g_sound.u_evt_merge/n1433_s3/I2
15.480 | 0.469 | tINS | RR | 1 | R37C16[3][A] | g_sound.u_evt_merge/n1433_s3/F
15.622 | 0.142 | tNET | RR | 1 | R37C15[3][B] | g_sound.u_evt_merge/n1433_s2/I2
16.070 | 0.448 | tINS | RR | 1 | R37C15[3][B] | g_sound.u_evt_merge/n1433_s2/F
16.072 | 0.002 | tNET | RR | 1 | R37C15[2][A] | g_sound.u_evt_merge/n1433_s1/I3
16.546 | 0.474 | tINS | RR | 1 | R37C15[2][A] | g_sound.u_evt_merge/n1433_s1/F
16.858 | 0.313 | tNET | RR | 1 | R37C18[2][B] | g_sound.u_evt_merge/n1433_s0/I3
17.273 | 0.415 | tINS | RR | 38 | R37C18[2][B] | g_sound.u_evt_merge/n1433_s0/F
18.106 | 0.833 | tNET | RR | 1 | R35C6[0][A] | g_sound.u_evt_merge/mem_s3593/I3
18.571 | 0.465 | tINS | RR | 1 | R35C6[0][A] | g_sound.u_evt_merge/mem_s3593/F
18.915 | 0.344 | tNET | RR | 1 | R31C6[1][B] | g_sound.u_evt_merge/mem_s3570/I2
19.379 | 0.465 | tINS | RR | 8 | R31C6[1][B] | g_sound.u_evt_merge/mem_s3570/F
19.832 | 0.452 | tNET | RR | 1 | R31C12[2][A] | g_sound.u_evt_merge/mem_s3546/I2
20.296 | 0.465 | tINS | RR | 70 | R31C12[2][A] | g_sound.u_evt_merge/mem_s3546/F
20.881 | 0.585 | tNET | RR | 1 | R31C8[2][B] | g_sound.u_evt_merge/mem_s3663/I3
21.118 | 0.236 | tINS | RR | 13 | R31C8[2][B] | g_sound.u_evt_merge/mem_s3663/F
21.487 | 0.369 | tNET | RR | 1 | R31C11[2][B] | g_sound.u_evt_merge/mem_s3075/I1
21.960 | 0.474 | tINS | RR | 50 | R31C11[2][B] | g_sound.u_evt_merge/mem_s3075/F
23.937 | 1.977 | tNET | RR | 1 | R33C20[1][B] | g_sound.u_evt_merge/mem_mem_RAMREG_1_G[29]_s0/CE

Data Required Path:

AT | DELAY | TYPE | RF | FANOUT | LOC | NODE
20.000 | 20.000 | | | | | active clock edge time
20.000 | 0.000 | | | | | clk_sys
20.000 | 0.000 | tCL | RR | 1 | IOB117[B] | clk_ibuf/I
21.288 | 1.288 | tINS | RR | 15774 | IOB117[B] | clk_ibuf/O
24.596 | 3.307 | tNET | RR | 1 | R33C20[1][B] | g_sound.u_evt_merge/mem_mem_RAMREG_1_G[29]_s0/CLK
24.316 | -0.280 | tSu | | 1 | R33C20[1][B] | g_sound.u_evt_merge/mem_mem_RAMREG_1_G[29]_s0

Path Statistics:

Clock Skew | 0.017
Setup Relationship | 20.000
Logic Level | 20
Arrival Clock Path Delay | cell: 1.288, 28.136%; route: 3.291, 71.864%
Arrival Data Path Delay | cell: 7.605, 39.285%; route: 11.409, 58.937%; tC2Q: 0.344, 1.778%
Required Clock Path Delay | cell: 1.288, 28.033%; route: 3.307, 71.967%

### Path12

Path Summary:

Slack | 0.393
Data Arrival Time | 23.914
Data Required Time | 24.307
From | g_sound.u_evt_merge/cnt_q_0_s0
To | g_sound.u_evt_merge/mem_mem_RAMREG_4_G[40]_s0
Launch Clk | clk_sys:[R]
Latch Clk | clk_sys:[R]

Data Arrival Path:

AT | DELAY | TYPE | RF | FANOUT | LOC | NODE
0.000 | 0.000 | | | | | active clock edge time
0.000 | 0.000 | | | | | clk_sys
0.000 | 0.000 | tCL | RR | 1 | IOB117[B] | clk_ibuf/I
1.288 | 1.288 | tINS | RR | 15774 | IOB117[B] | clk_ibuf/O
4.579 | 3.291 | tNET | RR | 1 | R37C18[2][A] | g_sound.u_evt_merge/cnt_q_0_s0/CLK
4.923 | 0.344 | tC2Q | RR | 6 | R37C18[2][A] | g_sound.u_evt_merge/cnt_q_0_s0/Q
5.276 | 0.353 | tNET | RR | 1 | R33C18[0][A] | g_sound.u_evt_merge/cnt_after_pop_5_s1/I0
5.750 | 0.474 | tINS | RR | 5 | R33C18[0][A] | g_sound.u_evt_merge/cnt_after_pop_5_s1/F
6.067 | 0.317 | tNET | RR | 1 | R33C16[1][B] | g_sound.u_evt_merge/cnt_after_pop_8_s1/I3
6.541 | 0.474 | tINS | RR | 5 | R33C16[1][B] | g_sound.u_evt_merge/cnt_after_pop_8_s1/F
6.692 | 0.151 | tNET | RR | 1 | R33C17[1][A] | g_sound.u_evt_merge/cnt_after_pop_11_s1/I3
7.107 | 0.415 | tINS | RR | 5 | R33C17[1][A] | g_sound.u_evt_merge/cnt_after_pop_11_s1/F
7.255 | 0.149 | tNET | RR | 1 | R33C18[2][A] | g_sound.u_evt_merge/cnt_after_pop_13_s2/I3
7.670 | 0.415 | tINS | RR | 5 | R33C18[2][A] | g_sound.u_evt_merge/cnt_after_pop_13_s2/F
8.145 | 0.475 | tNET | RR | 1 | R33C15[0][A] | g_sound.u_evt_merge/pop_now_s2/I3
8.381 | 0.236 | tINS | RR | 89 | R33C15[0][A] | g_sound.u_evt_merge/pop_now_s2/F
12.717 | 4.336 | tNET | RR | 1 | R34C16[0][B] | g_sound.u_evt_merge/cnt_after_pop_1_s0/I1
12.953 | 0.236 | tINS | RR | 2 | R34C16[0][B] | g_sound.u_evt_merge/cnt_after_pop_1_s0/F
13.300 | 0.346 | tNET | RR | 2 | R37C16[0][B] | g_sound.u_evt_merge/cnt_next_1_s/I0
13.806 | 0.506 | tINS | RF | 1 | R37C16[0][B] | g_sound.u_evt_merge/cnt_next_1_s/COUT
13.806 | 0.000 | tNET | FF | 2 | R37C16[1][A] | g_sound.u_evt_merge/cnt_next_2_s/CIN
13.851 | 0.045 | tINS | FR | 1 | R37C16[1][A] | g_sound.u_evt_merge/cnt_next_2_s/COUT
13.851 | 0.000 | tNET | RR | 2 | R37C16[1][B] | g_sound.u_evt_merge/cnt_next_3_s/CIN
13.896 | 0.045 | tINS | RR | 1 | R37C16[1][B] | g_sound.u_evt_merge/cnt_next_3_s/COUT
13.896 | 0.000 | tNET | RR | 2 | R37C16[2][A] | g_sound.u_evt_merge/cnt_next_4_s/CIN
13.941 | 0.045 | tINS | RR | 1 | R37C16[2][A] | g_sound.u_evt_merge/cnt_next_4_s/COUT
13.941 | 0.000 | tNET | RR | 2 | R37C16[2][B] | g_sound.u_evt_merge/cnt_next_5_s/CIN
13.986 | 0.045 | tINS | RR | 1 | R37C16[2][B] | g_sound.u_evt_merge/cnt_next_5_s/COUT
13.986 | 0.000 | tNET | RR | 2 | R37C17[0][A] | g_sound.u_evt_merge/cnt_next_6_s/CIN
14.031 | 0.045 | tINS | RR | 1 | R37C17[0][A] | g_sound.u_evt_merge/cnt_next_6_s/COUT
14.031 | 0.000 | tNET | RR | 2 | R37C17[0][B] | g_sound.u_evt_merge/cnt_next_7_s/CIN
14.298 | 0.267 | tINS | RR | 1 | R37C17[0][B] | g_sound.u_evt_merge/cnt_next_7_s/SUM
14.422 | 0.124 | tNET | RR | 1 | R37C17[3][B] | g_sound.u_evt_merge/n1433_s4/I3
14.869 | 0.448 | tINS | RR | 1 | R37C17[3][B] | g_sound.u_evt_merge/n1433_s4/F
15.011 | 0.142 | tNET | RR | 1 | R37C16[3][A] | g_sound.u_evt_merge/n1433_s3/I2
15.480 | 0.469 | tINS | RR | 1 | R37C16[3][A] | g_sound.u_evt_merge/n1433_s3/F
15.622 | 0.142 | tNET | RR | 1 | R37C15[3][B] | g_sound.u_evt_merge/n1433_s2/I2
16.070 | 0.448 | tINS | RR | 1 | R37C15[3][B] | g_sound.u_evt_merge/n1433_s2/F
16.072 | 0.002 | tNET | RR | 1 | R37C15[2][A] | g_sound.u_evt_merge/n1433_s1/I3
16.546 | 0.474 | tINS | RR | 1 | R37C15[2][A] | g_sound.u_evt_merge/n1433_s1/F
16.858 | 0.313 | tNET | RR | 1 | R37C18[2][B] | g_sound.u_evt_merge/n1433_s0/I3
17.273 | 0.415 | tINS | RR | 38 | R37C18[2][B] | g_sound.u_evt_merge/n1433_s0/F
18.106 | 0.833 | tNET | RR | 1 | R35C6[0][A] | g_sound.u_evt_merge/mem_s3593/I3
18.571 | 0.465 | tINS | RR | 1 | R35C6[0][A] | g_sound.u_evt_merge/mem_s3593/F
18.915 | 0.344 | tNET | RR | 1 | R31C6[1][B] | g_sound.u_evt_merge/mem_s3570/I2
19.379 | 0.465 | tINS | RR | 8 | R31C6[1][B] | g_sound.u_evt_merge/mem_s3570/F
19.953 | 0.574 | tNET | RR | 1 | R31C12[3][B] | g_sound.u_evt_merge/mem_s3512/I2
20.401 | 0.448 | tINS | RR | 70 | R31C12[3][B] | g_sound.u_evt_merge/mem_s3512/F
20.896 | 0.495 | tNET | RR | 1 | R31C9[2][B] | g_sound.u_evt_merge/mem_s3662/I3
21.361 | 0.465 | tINS | RR | 13 | R31C9[2][B] | g_sound.u_evt_merge/mem_s3662/F
21.734 | 0.373 | tNET | RR | 1 | R31C12[3][A] | g_sound.u_evt_merge/mem_s3081/I1
22.182 | 0.448 | tINS | RR | 50 | R31C12[3][A] | g_sound.u_evt_merge/mem_s3081/F
23.914 | 1.732 | tNET | RR | 1 | R35C3[2][A] | g_sound.u_evt_merge/mem_mem_RAMREG_4_G[40]_s0/CE

Data Required Path:

AT | DELAY | TYPE | RF | FANOUT | LOC | NODE
20.000 | 20.000 | | | | | active clock edge time
20.000 | 0.000 | | | | | clk_sys
20.000 | 0.000 | tCL | RR | 1 | IOB117[B] | clk_ibuf/I
21.288 | 1.288 | tINS | RR | 15774 | IOB117[B] | clk_ibuf/O
24.587 | 3.299 | tNET | RR | 1 | R35C3[2][A] | g_sound.u_evt_merge/mem_mem_RAMREG_4_G[40]_s0/CLK
24.307 | -0.280 | tSu | | 1 | R35C3[2][A] | g_sound.u_evt_merge/mem_mem_RAMREG_4_G[40]_s0

Path Statistics:

Clock Skew | 0.008
Setup Relationship | 20.000
Logic Level | 20
Arrival Clock Path Delay | cell: 1.288, 28.136%; route: 3.291, 71.864%
Arrival Data Path Delay | cell: 7.791, 40.292%; route: 11.201, 57.928%; tC2Q: 0.344, 1.780%
Required Clock Path Delay | cell: 1.288, 28.084%; route: 3.299, 71.916%

### Path13

Path Summary:

Slack | 0.520
Data Arrival Time | 23.787
Data Required Time | 24.307
From | g_sound.u_evt_merge/cnt_q_0_s0
To | g_sound.u_evt_merge/mem_mem_RAMREG_1_G[10]_s0
Launch Clk | clk_sys:[R]
Latch Clk | clk_sys:[R]

Data Arrival Path:

AT | DELAY | TYPE | RF | FANOUT | LOC | NODE
0.000 | 0.000 | | | | | active clock edge time
0.000 | 0.000 | | | | | clk_sys
0.000 | 0.000 | tCL | RR | 1 | IOB117[B] | clk_ibuf/I
1.288 | 1.288 | tINS | RR | 15774 | IOB117[B] | clk_ibuf/O
4.579 | 3.291 | tNET | RR | 1 | R37C18[2][A] | g_sound.u_evt_merge/cnt_q_0_s0/CLK
4.923 | 0.344 | tC2Q | RR | 6 | R37C18[2][A] | g_sound.u_evt_merge/cnt_q_0_s0/Q
5.276 | 0.353 | tNET | RR | 1 | R33C18[0][A] | g_sound.u_evt_merge/cnt_after_pop_5_s1/I0
5.750 | 0.474 | tINS | RR | 5 | R33C18[0][A] | g_sound.u_evt_merge/cnt_after_pop_5_s1/F
6.067 | 0.317 | tNET | RR | 1 | R33C16[1][B] | g_sound.u_evt_merge/cnt_after_pop_8_s1/I3
6.541 | 0.474 | tINS | RR | 5 | R33C16[1][B] | g_sound.u_evt_merge/cnt_after_pop_8_s1/F
6.692 | 0.151 | tNET | RR | 1 | R33C17[1][A] | g_sound.u_evt_merge/cnt_after_pop_11_s1/I3
7.107 | 0.415 | tINS | RR | 5 | R33C17[1][A] | g_sound.u_evt_merge/cnt_after_pop_11_s1/F
7.255 | 0.149 | tNET | RR | 1 | R33C18[2][A] | g_sound.u_evt_merge/cnt_after_pop_13_s2/I3
7.670 | 0.415 | tINS | RR | 5 | R33C18[2][A] | g_sound.u_evt_merge/cnt_after_pop_13_s2/F
8.145 | 0.475 | tNET | RR | 1 | R33C15[0][A] | g_sound.u_evt_merge/pop_now_s2/I3
8.381 | 0.236 | tINS | RR | 89 | R33C15[0][A] | g_sound.u_evt_merge/pop_now_s2/F
12.717 | 4.336 | tNET | RR | 1 | R34C16[0][B] | g_sound.u_evt_merge/cnt_after_pop_1_s0/I1
12.953 | 0.236 | tINS | RR | 2 | R34C16[0][B] | g_sound.u_evt_merge/cnt_after_pop_1_s0/F
13.300 | 0.346 | tNET | RR | 2 | R37C16[0][B] | g_sound.u_evt_merge/cnt_next_1_s/I0
13.806 | 0.506 | tINS | RF | 1 | R37C16[0][B] | g_sound.u_evt_merge/cnt_next_1_s/COUT
13.806 | 0.000 | tNET | FF | 2 | R37C16[1][A] | g_sound.u_evt_merge/cnt_next_2_s/CIN
13.851 | 0.045 | tINS | FR | 1 | R37C16[1][A] | g_sound.u_evt_merge/cnt_next_2_s/COUT
13.851 | 0.000 | tNET | RR | 2 | R37C16[1][B] | g_sound.u_evt_merge/cnt_next_3_s/CIN
13.896 | 0.045 | tINS | RR | 1 | R37C16[1][B] | g_sound.u_evt_merge/cnt_next_3_s/COUT
13.896 | 0.000 | tNET | RR | 2 | R37C16[2][A] | g_sound.u_evt_merge/cnt_next_4_s/CIN
13.941 | 0.045 | tINS | RR | 1 | R37C16[2][A] | g_sound.u_evt_merge/cnt_next_4_s/COUT
13.941 | 0.000 | tNET | RR | 2 | R37C16[2][B] | g_sound.u_evt_merge/cnt_next_5_s/CIN
13.986 | 0.045 | tINS | RR | 1 | R37C16[2][B] | g_sound.u_evt_merge/cnt_next_5_s/COUT
13.986 | 0.000 | tNET | RR | 2 | R37C17[0][A] | g_sound.u_evt_merge/cnt_next_6_s/CIN
14.031 | 0.045 | tINS | RR | 1 | R37C17[0][A] | g_sound.u_evt_merge/cnt_next_6_s/COUT
14.031 | 0.000 | tNET | RR | 2 | R37C17[0][B] | g_sound.u_evt_merge/cnt_next_7_s/CIN
14.298 | 0.267 | tINS | RR | 1 | R37C17[0][B] | g_sound.u_evt_merge/cnt_next_7_s/SUM
14.422 | 0.124 | tNET | RR | 1 | R37C17[3][B] | g_sound.u_evt_merge/n1433_s4/I3
14.869 | 0.448 | tINS | RR | 1 | R37C17[3][B] | g_sound.u_evt_merge/n1433_s4/F
15.011 | 0.142 | tNET | RR | 1 | R37C16[3][A] | g_sound.u_evt_merge/n1433_s3/I2
15.480 | 0.469 | tINS | RR | 1 | R37C16[3][A] | g_sound.u_evt_merge/n1433_s3/F
15.622 | 0.142 | tNET | RR | 1 | R37C15[3][B] | g_sound.u_evt_merge/n1433_s2/I2
16.070 | 0.448 | tINS | RR | 1 | R37C15[3][B] | g_sound.u_evt_merge/n1433_s2/F
16.072 | 0.002 | tNET | RR | 1 | R37C15[2][A] | g_sound.u_evt_merge/n1433_s1/I3
16.546 | 0.474 | tINS | RR | 1 | R37C15[2][A] | g_sound.u_evt_merge/n1433_s1/F
16.858 | 0.313 | tNET | RR | 1 | R37C18[2][B] | g_sound.u_evt_merge/n1433_s0/I3
17.273 | 0.415 | tINS | RR | 38 | R37C18[2][B] | g_sound.u_evt_merge/n1433_s0/F
18.106 | 0.833 | tNET | RR | 1 | R35C6[0][A] | g_sound.u_evt_merge/mem_s3593/I3
18.571 | 0.465 | tINS | RR | 1 | R35C6[0][A] | g_sound.u_evt_merge/mem_s3593/F
18.915 | 0.344 | tNET | RR | 1 | R31C6[1][B] | g_sound.u_evt_merge/mem_s3570/I2
19.379 | 0.465 | tINS | RR | 8 | R31C6[1][B] | g_sound.u_evt_merge/mem_s3570/F
19.832 | 0.452 | tNET | RR | 1 | R31C12[2][A] | g_sound.u_evt_merge/mem_s3546/I2
20.296 | 0.465 | tINS | RR | 70 | R31C12[2][A] | g_sound.u_evt_merge/mem_s3546/F
20.881 | 0.585 | tNET | RR | 1 | R31C8[2][B] | g_sound.u_evt_merge/mem_s3663/I3
21.118 | 0.236 | tINS | RR | 13 | R31C8[2][B] | g_sound.u_evt_merge/mem_s3663/F
21.487 | 0.369 | tNET | RR | 1 | R31C11[2][B] | g_sound.u_evt_merge/mem_s3075/I1
21.960 | 0.474 | tINS | RR | 50 | R31C11[2][B] | g_sound.u_evt_merge/mem_s3075/F
23.787 | 1.827 | tNET | RR | 1 | R36C17[3][B] | g_sound.u_evt_merge/mem_mem_RAMREG_1_G[10]_s0/CE

Data Required Path:

AT | DELAY | TYPE | RF | FANOUT | LOC | NODE
20.000 | 20.000 | | | | | active clock edge time
20.000 | 0.000 | | | | | clk_sys
20.000 | 0.000 | tCL | RR | 1 | IOB117[B] | clk_ibuf/I
21.288 | 1.288 | tINS | RR | 15774 | IOB117[B] | clk_ibuf/O
24.587 | 3.299 | tNET | RR | 1 | R36C17[3][B] | g_sound.u_evt_merge/mem_mem_RAMREG_1_G[10]_s0/CLK
24.307 | -0.280 | tSu | | 1 | R36C17[3][B] | g_sound.u_evt_merge/mem_mem_RAMREG_1_G[10]_s0

Path Statistics:

Clock Skew | 0.008
Setup Relationship | 20.000
Logic Level | 20
Arrival Clock Path Delay | cell: 1.288, 28.136%; route: 3.291, 71.864%
Arrival Data Path Delay | cell: 7.605, 39.592%; route: 11.259, 58.615%; tC2Q: 0.344, 1.792%
Required Clock Path Delay | cell: 1.288, 28.084%; route: 3.299, 71.916%

### Path14

Path Summary:

Slack | 0.520
Data Arrival Time | 23.787
Data Required Time | 24.307
From | g_sound.u_evt_merge/cnt_q_0_s0
To | g_sound.u_evt_merge/mem_mem_RAMREG_1_G[7]_s0
Launch Clk | clk_sys:[R]
Latch Clk | clk_sys:[R]

Data Arrival Path:

AT | DELAY | TYPE | RF | FANOUT | LOC | NODE
0.000 | 0.000 | | | | | active clock edge time
0.000 | 0.000 | | | | | clk_sys
0.000 | 0.000 | tCL | RR | 1 | IOB117[B] | clk_ibuf/I
1.288 | 1.288 | tINS | RR | 15774 | IOB117[B] | clk_ibuf/O
4.579 | 3.291 | tNET | RR | 1 | R37C18[2][A] | g_sound.u_evt_merge/cnt_q_0_s0/CLK
4.923 | 0.344 | tC2Q | RR | 6 | R37C18[2][A] | g_sound.u_evt_merge/cnt_q_0_s0/Q
5.276 | 0.353 | tNET | RR | 1 | R33C18[0][A] | g_sound.u_evt_merge/cnt_after_pop_5_s1/I0
5.750 | 0.474 | tINS | RR | 5 | R33C18[0][A] | g_sound.u_evt_merge/cnt_after_pop_5_s1/F
6.067 | 0.317 | tNET | RR | 1 | R33C16[1][B] | g_sound.u_evt_merge/cnt_after_pop_8_s1/I3
6.541 | 0.474 | tINS | RR | 5 | R33C16[1][B] | g_sound.u_evt_merge/cnt_after_pop_8_s1/F
6.692 | 0.151 | tNET | RR | 1 | R33C17[1][A] | g_sound.u_evt_merge/cnt_after_pop_11_s1/I3
7.107 | 0.415 | tINS | RR | 5 | R33C17[1][A] | g_sound.u_evt_merge/cnt_after_pop_11_s1/F
7.255 | 0.149 | tNET | RR | 1 | R33C18[2][A] | g_sound.u_evt_merge/cnt_after_pop_13_s2/I3
7.670 | 0.415 | tINS | RR | 5 | R33C18[2][A] | g_sound.u_evt_merge/cnt_after_pop_13_s2/F
8.145 | 0.475 | tNET | RR | 1 | R33C15[0][A] | g_sound.u_evt_merge/pop_now_s2/I3
8.381 | 0.236 | tINS | RR | 89 | R33C15[0][A] | g_sound.u_evt_merge/pop_now_s2/F
12.717 | 4.336 | tNET | RR | 1 | R34C16[0][B] | g_sound.u_evt_merge/cnt_after_pop_1_s0/I1
12.953 | 0.236 | tINS | RR | 2 | R34C16[0][B] | g_sound.u_evt_merge/cnt_after_pop_1_s0/F
13.300 | 0.346 | tNET | RR | 2 | R37C16[0][B] | g_sound.u_evt_merge/cnt_next_1_s/I0
13.806 | 0.506 | tINS | RF | 1 | R37C16[0][B] | g_sound.u_evt_merge/cnt_next_1_s/COUT
13.806 | 0.000 | tNET | FF | 2 | R37C16[1][A] | g_sound.u_evt_merge/cnt_next_2_s/CIN
13.851 | 0.045 | tINS | FR | 1 | R37C16[1][A] | g_sound.u_evt_merge/cnt_next_2_s/COUT
13.851 | 0.000 | tNET | RR | 2 | R37C16[1][B] | g_sound.u_evt_merge/cnt_next_3_s/CIN
13.896 | 0.045 | tINS | RR | 1 | R37C16[1][B] | g_sound.u_evt_merge/cnt_next_3_s/COUT
13.896 | 0.000 | tNET | RR | 2 | R37C16[2][A] | g_sound.u_evt_merge/cnt_next_4_s/CIN
13.941 | 0.045 | tINS | RR | 1 | R37C16[2][A] | g_sound.u_evt_merge/cnt_next_4_s/COUT
13.941 | 0.000 | tNET | RR | 2 | R37C16[2][B] | g_sound.u_evt_merge/cnt_next_5_s/CIN
13.986 | 0.045 | tINS | RR | 1 | R37C16[2][B] | g_sound.u_evt_merge/cnt_next_5_s/COUT
13.986 | 0.000 | tNET | RR | 2 | R37C17[0][A] | g_sound.u_evt_merge/cnt_next_6_s/CIN
14.031 | 0.045 | tINS | RR | 1 | R37C17[0][A] | g_sound.u_evt_merge/cnt_next_6_s/COUT
14.031 | 0.000 | tNET | RR | 2 | R37C17[0][B] | g_sound.u_evt_merge/cnt_next_7_s/CIN
14.298 | 0.267 | tINS | RR | 1 | R37C17[0][B] | g_sound.u_evt_merge/cnt_next_7_s/SUM
14.422 | 0.124 | tNET | RR | 1 | R37C17[3][B] | g_sound.u_evt_merge/n1433_s4/I3
14.869 | 0.448 | tINS | RR | 1 | R37C17[3][B] | g_sound.u_evt_merge/n1433_s4/F
15.011 | 0.142 | tNET | RR | 1 | R37C16[3][A] | g_sound.u_evt_merge/n1433_s3/I2
15.480 | 0.469 | tINS | RR | 1 | R37C16[3][A] | g_sound.u_evt_merge/n1433_s3/F
15.622 | 0.142 | tNET | RR | 1 | R37C15[3][B] | g_sound.u_evt_merge/n1433_s2/I2
16.070 | 0.448 | tINS | RR | 1 | R37C15[3][B] | g_sound.u_evt_merge/n1433_s2/F
16.072 | 0.002 | tNET | RR | 1 | R37C15[2][A] | g_sound.u_evt_merge/n1433_s1/I3
16.546 | 0.474 | tINS | RR | 1 | R37C15[2][A] | g_sound.u_evt_merge/n1433_s1/F
16.858 | 0.313 | tNET | RR | 1 | R37C18[2][B] | g_sound.u_evt_merge/n1433_s0/I3
17.273 | 0.415 | tINS | RR | 38 | R37C18[2][B] | g_sound.u_evt_merge/n1433_s0/F
18.106 | 0.833 | tNET | RR | 1 | R35C6[0][A] | g_sound.u_evt_merge/mem_s3593/I3
18.571 | 0.465 | tINS | RR | 1 | R35C6[0][A] | g_sound.u_evt_merge/mem_s3593/F
18.915 | 0.344 | tNET | RR | 1 | R31C6[1][B] | g_sound.u_evt_merge/mem_s3570/I2
19.379 | 0.465 | tINS | RR | 8 | R31C6[1][B] | g_sound.u_evt_merge/mem_s3570/F
19.832 | 0.452 | tNET | RR | 1 | R31C12[2][A] | g_sound.u_evt_merge/mem_s3546/I2
20.296 | 0.465 | tINS | RR | 70 | R31C12[2][A] | g_sound.u_evt_merge/mem_s3546/F
20.881 | 0.585 | tNET | RR | 1 | R31C8[2][B] | g_sound.u_evt_merge/mem_s3663/I3
21.118 | 0.236 | tINS | RR | 13 | R31C8[2][B] | g_sound.u_evt_merge/mem_s3663/F
21.487 | 0.369 | tNET | RR | 1 | R31C11[2][B] | g_sound.u_evt_merge/mem_s3075/I1
21.960 | 0.474 | tINS | RR | 50 | R31C11[2][B] | g_sound.u_evt_merge/mem_s3075/F
23.787 | 1.827 | tNET | RR | 1 | R36C17[2][A] | g_sound.u_evt_merge/mem_mem_RAMREG_1_G[7]_s0/CE

Data Required Path:

AT | DELAY | TYPE | RF | FANOUT | LOC | NODE
20.000 | 20.000 | | | | | active clock edge time
20.000 | 0.000 | | | | | clk_sys
20.000 | 0.000 | tCL | RR | 1 | IOB117[B] | clk_ibuf/I
21.288 | 1.288 | tINS | RR | 15774 | IOB117[B] | clk_ibuf/O
24.587 | 3.299 | tNET | RR | 1 | R36C17[2][A] | g_sound.u_evt_merge/mem_mem_RAMREG_1_G[7]_s0/CLK
24.307 | -0.280 | tSu | | 1 | R36C17[2][A] | g_sound.u_evt_merge/mem_mem_RAMREG_1_G[7]_s0

Path Statistics:

Clock Skew | 0.008
Setup Relationship | 20.000
Logic Level | 20
Arrival Clock Path Delay | cell: 1.288, 28.136%; route: 3.291, 71.864%
Arrival Data Path Delay | cell: 7.605, 39.592%; route: 11.259, 58.615%; tC2Q: 0.344, 1.792%
Required Clock Path Delay | cell: 1.288, 28.084%; route: 3.299, 71.916%

### Path15

Path Summary:

Slack | 0.520
Data Arrival Time | 23.787
Data Required Time | 24.307
From | g_sound.u_evt_merge/cnt_q_0_s0
To | g_sound.u_evt_merge/mem_mem_RAMREG_1_G[5]_s0
Launch Clk | clk_sys:[R]
Latch Clk | clk_sys:[R]

Data Arrival Path:

AT | DELAY | TYPE | RF | FANOUT | LOC | NODE
0.000 | 0.000 | | | | | active clock edge time
0.000 | 0.000 | | | | | clk_sys
0.000 | 0.000 | tCL | RR | 1 | IOB117[B] | clk_ibuf/I
1.288 | 1.288 | tINS | RR | 15774 | IOB117[B] | clk_ibuf/O
4.579 | 3.291 | tNET | RR | 1 | R37C18[2][A] | g_sound.u_evt_merge/cnt_q_0_s0/CLK
4.923 | 0.344 | tC2Q | RR | 6 | R37C18[2][A] | g_sound.u_evt_merge/cnt_q_0_s0/Q
5.276 | 0.353 | tNET | RR | 1 | R33C18[0][A] | g_sound.u_evt_merge/cnt_after_pop_5_s1/I0
5.750 | 0.474 | tINS | RR | 5 | R33C18[0][A] | g_sound.u_evt_merge/cnt_after_pop_5_s1/F
6.067 | 0.317 | tNET | RR | 1 | R33C16[1][B] | g_sound.u_evt_merge/cnt_after_pop_8_s1/I3
6.541 | 0.474 | tINS | RR | 5 | R33C16[1][B] | g_sound.u_evt_merge/cnt_after_pop_8_s1/F
6.692 | 0.151 | tNET | RR | 1 | R33C17[1][A] | g_sound.u_evt_merge/cnt_after_pop_11_s1/I3
7.107 | 0.415 | tINS | RR | 5 | R33C17[1][A] | g_sound.u_evt_merge/cnt_after_pop_11_s1/F
7.255 | 0.149 | tNET | RR | 1 | R33C18[2][A] | g_sound.u_evt_merge/cnt_after_pop_13_s2/I3
7.670 | 0.415 | tINS | RR | 5 | R33C18[2][A] | g_sound.u_evt_merge/cnt_after_pop_13_s2/F
8.145 | 0.475 | tNET | RR | 1 | R33C15[0][A] | g_sound.u_evt_merge/pop_now_s2/I3
8.381 | 0.236 | tINS | RR | 89 | R33C15[0][A] | g_sound.u_evt_merge/pop_now_s2/F
12.717 | 4.336 | tNET | RR | 1 | R34C16[0][B] | g_sound.u_evt_merge/cnt_after_pop_1_s0/I1
12.953 | 0.236 | tINS | RR | 2 | R34C16[0][B] | g_sound.u_evt_merge/cnt_after_pop_1_s0/F
13.300 | 0.346 | tNET | RR | 2 | R37C16[0][B] | g_sound.u_evt_merge/cnt_next_1_s/I0
13.806 | 0.506 | tINS | RF | 1 | R37C16[0][B] | g_sound.u_evt_merge/cnt_next_1_s/COUT
13.806 | 0.000 | tNET | FF | 2 | R37C16[1][A] | g_sound.u_evt_merge/cnt_next_2_s/CIN
13.851 | 0.045 | tINS | FR | 1 | R37C16[1][A] | g_sound.u_evt_merge/cnt_next_2_s/COUT
13.851 | 0.000 | tNET | RR | 2 | R37C16[1][B] | g_sound.u_evt_merge/cnt_next_3_s/CIN
13.896 | 0.045 | tINS | RR | 1 | R37C16[1][B] | g_sound.u_evt_merge/cnt_next_3_s/COUT
13.896 | 0.000 | tNET | RR | 2 | R37C16[2][A] | g_sound.u_evt_merge/cnt_next_4_s/CIN
13.941 | 0.045 | tINS | RR | 1 | R37C16[2][A] | g_sound.u_evt_merge/cnt_next_4_s/COUT
13.941 | 0.000 | tNET | RR | 2 | R37C16[2][B] | g_sound.u_evt_merge/cnt_next_5_s/CIN
13.986 | 0.045 | tINS | RR | 1 | R37C16[2][B] | g_sound.u_evt_merge/cnt_next_5_s/COUT
13.986 | 0.000 | tNET | RR | 2 | R37C17[0][A] | g_sound.u_evt_merge/cnt_next_6_s/CIN
14.031 | 0.045 | tINS | RR | 1 | R37C17[0][A] | g_sound.u_evt_merge/cnt_next_6_s/COUT
14.031 | 0.000 | tNET | RR | 2 | R37C17[0][B] | g_sound.u_evt_merge/cnt_next_7_s/CIN
14.298 | 0.267 | tINS | RR | 1 | R37C17[0][B] | g_sound.u_evt_merge/cnt_next_7_s/SUM
14.422 | 0.124 | tNET | RR | 1 | R37C17[3][B] | g_sound.u_evt_merge/n1433_s4/I3
14.869 | 0.448 | tINS | RR | 1 | R37C17[3][B] | g_sound.u_evt_merge/n1433_s4/F
15.011 | 0.142 | tNET | RR | 1 | R37C16[3][A] | g_sound.u_evt_merge/n1433_s3/I2
15.480 | 0.469 | tINS | RR | 1 | R37C16[3][A] | g_sound.u_evt_merge/n1433_s3/F
15.622 | 0.142 | tNET | RR | 1 | R37C15[3][B] | g_sound.u_evt_merge/n1433_s2/I2
16.070 | 0.448 | tINS | RR | 1 | R37C15[3][B] | g_sound.u_evt_merge/n1433_s2/F
16.072 | 0.002 | tNET | RR | 1 | R37C15[2][A] | g_sound.u_evt_merge/n1433_s1/I3
16.546 | 0.474 | tINS | RR | 1 | R37C15[2][A] | g_sound.u_evt_merge/n1433_s1/F
16.858 | 0.313 | tNET | RR | 1 | R37C18[2][B] | g_sound.u_evt_merge/n1433_s0/I3
17.273 | 0.415 | tINS | RR | 38 | R37C18[2][B] | g_sound.u_evt_merge/n1433_s0/F
18.106 | 0.833 | tNET | RR | 1 | R35C6[0][A] | g_sound.u_evt_merge/mem_s3593/I3
18.571 | 0.465 | tINS | RR | 1 | R35C6[0][A] | g_sound.u_evt_merge/mem_s3593/F
18.915 | 0.344 | tNET | RR | 1 | R31C6[1][B] | g_sound.u_evt_merge/mem_s3570/I2
19.379 | 0.465 | tINS | RR | 8 | R31C6[1][B] | g_sound.u_evt_merge/mem_s3570/F
19.832 | 0.452 | tNET | RR | 1 | R31C12[2][A] | g_sound.u_evt_merge/mem_s3546/I2
20.296 | 0.465 | tINS | RR | 70 | R31C12[2][A] | g_sound.u_evt_merge/mem_s3546/F
20.881 | 0.585 | tNET | RR | 1 | R31C8[2][B] | g_sound.u_evt_merge/mem_s3663/I3
21.118 | 0.236 | tINS | RR | 13 | R31C8[2][B] | g_sound.u_evt_merge/mem_s3663/F
21.487 | 0.369 | tNET | RR | 1 | R31C11[2][B] | g_sound.u_evt_merge/mem_s3075/I1
21.960 | 0.474 | tINS | RR | 50 | R31C11[2][B] | g_sound.u_evt_merge/mem_s3075/F
23.787 | 1.827 | tNET | RR | 1 | R36C17[3][A] | g_sound.u_evt_merge/mem_mem_RAMREG_1_G[5]_s0/CE

Data Required Path:

AT | DELAY | TYPE | RF | FANOUT | LOC | NODE
20.000 | 20.000 | | | | | active clock edge time
20.000 | 0.000 | | | | | clk_sys
20.000 | 0.000 | tCL | RR | 1 | IOB117[B] | clk_ibuf/I
21.288 | 1.288 | tINS | RR | 15774 | IOB117[B] | clk_ibuf/O
24.587 | 3.299 | tNET | RR | 1 | R36C17[3][A] | g_sound.u_evt_merge/mem_mem_RAMREG_1_G[5]_s0/CLK
24.307 | -0.280 | tSu | | 1 | R36C17[3][A] | g_sound.u_evt_merge/mem_mem_RAMREG_1_G[5]_s0

Path Statistics:

Clock Skew | 0.008
Setup Relationship | 20.000
Logic Level | 20
Arrival Clock Path Delay | cell: 1.288, 28.136%; route: 3.291, 71.864%
Arrival Data Path Delay | cell: 7.605, 39.592%; route: 11.259, 58.615%; tC2Q: 0.344, 1.792%
Required Clock Path Delay | cell: 1.288, 28.084%; route: 3.299, 71.916%

### Path16

Path Summary:

Slack | 0.537
Data Arrival Time | 20.217
Data Required Time | 20.754
From | g_sound.u_adc_farm/u_scan0/sample_channel_0_s0
To | g_sound.u_calib1/n840_s
Launch Clk | clk_sys:[R]
Latch Clk | clk_sys:[R]

Data Arrival Path:

AT | DELAY | TYPE | RF | FANOUT | LOC | NODE
0.000 | 0.000 | | | | | active clock edge time
0.000 | 0.000 | | | | | clk_sys
0.000 | 0.000 | tCL | RR | 1 | IOB117[B] | clk_ibuf/I
1.288 | 1.288 | tINS | RR | 15774 | IOB117[B] | clk_ibuf/O
4.142 | 2.854 | tNET | RR | 1 | R8C82[0][B] | g_sound.u_adc_farm/u_scan0/sample_channel_0_s0/CLK
4.473 | 0.331 | tC2Q | RF | 141 | R8C82[0][B] | g_sound.u_adc_farm/u_scan0/sample_channel_0_s0/Q
10.513 | 6.040 | tNET | FF | 1 | R31C20[0][B] | g_sound.u_calib1/span_r_RAMOUT_28_G[0]_s0/S0
10.740 | 0.227 | tINS | FR | 3 | R31C20[0][B] | g_sound.u_calib1/span_r_RAMOUT_28_G[0]_s0/O
11.774 | 1.034 | tNET | RR | 1 | R30C39[2][A] | g_sound.u_calib1/dclamp_9_s19/I1
12.248 | 0.474 | tINS | RR | 1 | R30C39[2][A] | g_sound.u_calib1/dclamp_9_s19/F
12.250 | 0.002 | tNET | RR | 1 | R30C39[1][B] | g_sound.u_calib1/dclamp_9_s16/I3
12.665 | 0.415 | tINS | RR | 1 | R30C39[1][B] | g_sound.u_calib1/dclamp_9_s16/F
12.807 | 0.142 | tNET | RR | 1 | R30C38[1][A] | g_sound.u_calib1/dclamp_9_s7/I2
13.043 | 0.236 | tINS | RR | 1 | R30C38[1][A] | g_sound.u_calib1/dclamp_9_s7/F
13.828 | 0.785 | tNET | RR | 1 | R30C26[0][B] | g_sound.u_calib1/dclamp_9_s4/I3
14.302 | 0.474 | tINS | RR | 13 | R30C26[0][B] | g_sound.u_calib1/dclamp_9_s4/F
15.158 | 0.856 | tNET | RR | 1 | R30C44[2][B] | g_sound.u_calib1/dclamp_7_s5/I3
15.623 | 0.465 | tINS | RR | 1 | R30C44[2][B] | g_sound.u_calib1/dclamp_7_s5/F
15.625 | 0.002 | tNET | RR | 1 | R30C44[3][A] | g_sound.u_calib1/dclamp_7_s4/I2
16.073 | 0.448 | tINS | RR | 1 | R30C44[3][A] | g_sound.u_calib1/dclamp_7_s4/F
16.214 | 0.142 | tNET | RR | 1 | R30C43[1][A] | g_sound.u_calib1/dclamp_7_s3/I1
16.451 | 0.236 | tINS | RR | 1 | R30C43[1][A] | g_sound.u_calib1/dclamp_7_s3/F
16.453 | 0.002 | tNET | RR | 1 | R30C43[3][B] | g_sound.u_calib1/dclamp_7_s2/I2
16.714 | 0.261 | tINS | RF | 8 | R30C43[3][B] | g_sound.u_calib1/dclamp_7_s2/F
17.005 | 0.291 | tNET | FF | 1 | R30C41[3][B] | g_sound.u_calib1/dclamp_1_s0/I2
17.379 | 0.373 | tINS | FR | 1 | R30C41[3][B] | g_sound.u_calib1/dclamp_1_s0/F
20.217 | 2.838 | tNET | RR | 1 | DSP_R28[6] | g_sound.u_calib1/n840_s/A[1]

Data Required Path:

AT | DELAY | TYPE | RF | FANOUT | LOC | NODE
20.000 | 20.000 | | | | | active clock edge time
20.000 | 0.000 | | | | | clk_sys
20.000 | 0.000 | tCL | RR | 1 | IOB117[B] | clk_ibuf/I
21.288 | 1.288 | tINS | RR | 15774 | IOB117[B] | clk_ibuf/O
24.133 | 2.845 | tNET | RR | 1 | DSP_R28[6] | g_sound.u_calib1/n840_s/CLK[0]
20.754 | -3.379 | tSu | | 1 | DSP_R28[6] | g_sound.u_calib1/n840_s

Path Statistics:

Clock Skew | -0.008
Setup Relationship | 20.000
Logic Level | 11
Arrival Clock Path Delay | cell: 1.288, 31.105%; route: 2.854, 68.895%
Arrival Data Path Delay | cell: 3.609, 22.451%; route: 12.135, 75.492%; tC2Q: 0.331, 2.058%
Required Clock Path Delay | cell: 1.288, 31.169%; route: 2.845, 68.831%

### Path17

Path Summary:

Slack | 0.566
Data Arrival Time | 23.741
Data Required Time | 24.307
From | g_sound.u_evt_merge/cnt_q_0_s0
To | g_sound.u_evt_merge/mem_mem_RAMREG_4_G[27]_s0
Launch Clk | clk_sys:[R]
Latch Clk | clk_sys:[R]

Data Arrival Path:

AT | DELAY | TYPE | RF | FANOUT | LOC | NODE
0.000 | 0.000 | | | | | active clock edge time
0.000 | 0.000 | | | | | clk_sys
0.000 | 0.000 | tCL | RR | 1 | IOB117[B] | clk_ibuf/I
1.288 | 1.288 | tINS | RR | 15774 | IOB117[B] | clk_ibuf/O
4.579 | 3.291 | tNET | RR | 1 | R37C18[2][A] | g_sound.u_evt_merge/cnt_q_0_s0/CLK
4.923 | 0.344 | tC2Q | RR | 6 | R37C18[2][A] | g_sound.u_evt_merge/cnt_q_0_s0/Q
5.276 | 0.353 | tNET | RR | 1 | R33C18[0][A] | g_sound.u_evt_merge/cnt_after_pop_5_s1/I0
5.750 | 0.474 | tINS | RR | 5 | R33C18[0][A] | g_sound.u_evt_merge/cnt_after_pop_5_s1/F
6.067 | 0.317 | tNET | RR | 1 | R33C16[1][B] | g_sound.u_evt_merge/cnt_after_pop_8_s1/I3
6.541 | 0.474 | tINS | RR | 5 | R33C16[1][B] | g_sound.u_evt_merge/cnt_after_pop_8_s1/F
6.692 | 0.151 | tNET | RR | 1 | R33C17[1][A] | g_sound.u_evt_merge/cnt_after_pop_11_s1/I3
7.107 | 0.415 | tINS | RR | 5 | R33C17[1][A] | g_sound.u_evt_merge/cnt_after_pop_11_s1/F
7.255 | 0.149 | tNET | RR | 1 | R33C18[2][A] | g_sound.u_evt_merge/cnt_after_pop_13_s2/I3
7.670 | 0.415 | tINS | RR | 5 | R33C18[2][A] | g_sound.u_evt_merge/cnt_after_pop_13_s2/F
8.145 | 0.475 | tNET | RR | 1 | R33C15[0][A] | g_sound.u_evt_merge/pop_now_s2/I3
8.381 | 0.236 | tINS | RR | 89 | R33C15[0][A] | g_sound.u_evt_merge/pop_now_s2/F
12.717 | 4.336 | tNET | RR | 1 | R34C16[0][B] | g_sound.u_evt_merge/cnt_after_pop_1_s0/I1
12.953 | 0.236 | tINS | RR | 2 | R34C16[0][B] | g_sound.u_evt_merge/cnt_after_pop_1_s0/F
13.300 | 0.346 | tNET | RR | 2 | R37C16[0][B] | g_sound.u_evt_merge/cnt_next_1_s/I0
13.806 | 0.506 | tINS | RF | 1 | R37C16[0][B] | g_sound.u_evt_merge/cnt_next_1_s/COUT
13.806 | 0.000 | tNET | FF | 2 | R37C16[1][A] | g_sound.u_evt_merge/cnt_next_2_s/CIN
13.851 | 0.045 | tINS | FR | 1 | R37C16[1][A] | g_sound.u_evt_merge/cnt_next_2_s/COUT
13.851 | 0.000 | tNET | RR | 2 | R37C16[1][B] | g_sound.u_evt_merge/cnt_next_3_s/CIN
13.896 | 0.045 | tINS | RR | 1 | R37C16[1][B] | g_sound.u_evt_merge/cnt_next_3_s/COUT
13.896 | 0.000 | tNET | RR | 2 | R37C16[2][A] | g_sound.u_evt_merge/cnt_next_4_s/CIN
13.941 | 0.045 | tINS | RR | 1 | R37C16[2][A] | g_sound.u_evt_merge/cnt_next_4_s/COUT
13.941 | 0.000 | tNET | RR | 2 | R37C16[2][B] | g_sound.u_evt_merge/cnt_next_5_s/CIN
13.986 | 0.045 | tINS | RR | 1 | R37C16[2][B] | g_sound.u_evt_merge/cnt_next_5_s/COUT
13.986 | 0.000 | tNET | RR | 2 | R37C17[0][A] | g_sound.u_evt_merge/cnt_next_6_s/CIN
14.031 | 0.045 | tINS | RR | 1 | R37C17[0][A] | g_sound.u_evt_merge/cnt_next_6_s/COUT
14.031 | 0.000 | tNET | RR | 2 | R37C17[0][B] | g_sound.u_evt_merge/cnt_next_7_s/CIN
14.298 | 0.267 | tINS | RR | 1 | R37C17[0][B] | g_sound.u_evt_merge/cnt_next_7_s/SUM
14.422 | 0.124 | tNET | RR | 1 | R37C17[3][B] | g_sound.u_evt_merge/n1433_s4/I3
14.869 | 0.448 | tINS | RR | 1 | R37C17[3][B] | g_sound.u_evt_merge/n1433_s4/F
15.011 | 0.142 | tNET | RR | 1 | R37C16[3][A] | g_sound.u_evt_merge/n1433_s3/I2
15.480 | 0.469 | tINS | RR | 1 | R37C16[3][A] | g_sound.u_evt_merge/n1433_s3/F
15.622 | 0.142 | tNET | RR | 1 | R37C15[3][B] | g_sound.u_evt_merge/n1433_s2/I2
16.070 | 0.448 | tINS | RR | 1 | R37C15[3][B] | g_sound.u_evt_merge/n1433_s2/F
16.072 | 0.002 | tNET | RR | 1 | R37C15[2][A] | g_sound.u_evt_merge/n1433_s1/I3
16.546 | 0.474 | tINS | RR | 1 | R37C15[2][A] | g_sound.u_evt_merge/n1433_s1/F
16.858 | 0.313 | tNET | RR | 1 | R37C18[2][B] | g_sound.u_evt_merge/n1433_s0/I3
17.273 | 0.415 | tINS | RR | 38 | R37C18[2][B] | g_sound.u_evt_merge/n1433_s0/F
18.106 | 0.833 | tNET | RR | 1 | R35C6[0][A] | g_sound.u_evt_merge/mem_s3593/I3
18.571 | 0.465 | tINS | RR | 1 | R35C6[0][A] | g_sound.u_evt_merge/mem_s3593/F
18.915 | 0.344 | tNET | RR | 1 | R31C6[1][B] | g_sound.u_evt_merge/mem_s3570/I2
19.379 | 0.465 | tINS | RR | 8 | R31C6[1][B] | g_sound.u_evt_merge/mem_s3570/F
19.953 | 0.574 | tNET | RR | 1 | R31C12[3][B] | g_sound.u_evt_merge/mem_s3512/I2
20.401 | 0.448 | tINS | RR | 70 | R31C12[3][B] | g_sound.u_evt_merge/mem_s3512/F
20.896 | 0.495 | tNET | RR | 1 | R31C9[2][B] | g_sound.u_evt_merge/mem_s3662/I3
21.361 | 0.465 | tINS | RR | 13 | R31C9[2][B] | g_sound.u_evt_merge/mem_s3662/F
21.734 | 0.373 | tNET | RR | 1 | R31C12[3][A] | g_sound.u_evt_merge/mem_s3081/I1
22.182 | 0.448 | tINS | RR | 50 | R31C12[3][A] | g_sound.u_evt_merge/mem_s3081/F
23.741 | 1.559 | tNET | RR | 1 | R33C3[2][A] | g_sound.u_evt_merge/mem_mem_RAMREG_4_G[27]_s0/CE

Data Required Path:

AT | DELAY | TYPE | RF | FANOUT | LOC | NODE
20.000 | 20.000 | | | | | active clock edge time
20.000 | 0.000 | | | | | clk_sys
20.000 | 0.000 | tCL | RR | 1 | IOB117[B] | clk_ibuf/I
21.288 | 1.288 | tINS | RR | 15774 | IOB117[B] | clk_ibuf/O
24.587 | 3.299 | tNET | RR | 1 | R33C3[2][A] | g_sound.u_evt_merge/mem_mem_RAMREG_4_G[27]_s0/CLK
24.307 | -0.280 | tSu | | 1 | R33C3[2][A] | g_sound.u_evt_merge/mem_mem_RAMREG_4_G[27]_s0

Path Statistics:

Clock Skew | 0.008
Setup Relationship | 20.000
Logic Level | 20
Arrival Clock Path Delay | cell: 1.288, 28.136%; route: 3.291, 71.864%
Arrival Data Path Delay | cell: 7.791, 40.656%; route: 11.027, 57.547%; tC2Q: 0.344, 1.797%
Required Clock Path Delay | cell: 1.288, 28.084%; route: 3.299, 71.916%

### Path18

Path Summary:

Slack | 0.566
Data Arrival Time | 23.741
Data Required Time | 24.307
From | g_sound.u_evt_merge/cnt_q_0_s0
To | g_sound.u_evt_merge/mem_mem_RAMREG_4_G[22]_s0
Launch Clk | clk_sys:[R]
Latch Clk | clk_sys:[R]

Data Arrival Path:

AT | DELAY | TYPE | RF | FANOUT | LOC | NODE
0.000 | 0.000 | | | | | active clock edge time
0.000 | 0.000 | | | | | clk_sys
0.000 | 0.000 | tCL | RR | 1 | IOB117[B] | clk_ibuf/I
1.288 | 1.288 | tINS | RR | 15774 | IOB117[B] | clk_ibuf/O
4.579 | 3.291 | tNET | RR | 1 | R37C18[2][A] | g_sound.u_evt_merge/cnt_q_0_s0/CLK
4.923 | 0.344 | tC2Q | RR | 6 | R37C18[2][A] | g_sound.u_evt_merge/cnt_q_0_s0/Q
5.276 | 0.353 | tNET | RR | 1 | R33C18[0][A] | g_sound.u_evt_merge/cnt_after_pop_5_s1/I0
5.750 | 0.474 | tINS | RR | 5 | R33C18[0][A] | g_sound.u_evt_merge/cnt_after_pop_5_s1/F
6.067 | 0.317 | tNET | RR | 1 | R33C16[1][B] | g_sound.u_evt_merge/cnt_after_pop_8_s1/I3
6.541 | 0.474 | tINS | RR | 5 | R33C16[1][B] | g_sound.u_evt_merge/cnt_after_pop_8_s1/F
6.692 | 0.151 | tNET | RR | 1 | R33C17[1][A] | g_sound.u_evt_merge/cnt_after_pop_11_s1/I3
7.107 | 0.415 | tINS | RR | 5 | R33C17[1][A] | g_sound.u_evt_merge/cnt_after_pop_11_s1/F
7.255 | 0.149 | tNET | RR | 1 | R33C18[2][A] | g_sound.u_evt_merge/cnt_after_pop_13_s2/I3
7.670 | 0.415 | tINS | RR | 5 | R33C18[2][A] | g_sound.u_evt_merge/cnt_after_pop_13_s2/F
8.145 | 0.475 | tNET | RR | 1 | R33C15[0][A] | g_sound.u_evt_merge/pop_now_s2/I3
8.381 | 0.236 | tINS | RR | 89 | R33C15[0][A] | g_sound.u_evt_merge/pop_now_s2/F
12.717 | 4.336 | tNET | RR | 1 | R34C16[0][B] | g_sound.u_evt_merge/cnt_after_pop_1_s0/I1
12.953 | 0.236 | tINS | RR | 2 | R34C16[0][B] | g_sound.u_evt_merge/cnt_after_pop_1_s0/F
13.300 | 0.346 | tNET | RR | 2 | R37C16[0][B] | g_sound.u_evt_merge/cnt_next_1_s/I0
13.806 | 0.506 | tINS | RF | 1 | R37C16[0][B] | g_sound.u_evt_merge/cnt_next_1_s/COUT
13.806 | 0.000 | tNET | FF | 2 | R37C16[1][A] | g_sound.u_evt_merge/cnt_next_2_s/CIN
13.851 | 0.045 | tINS | FR | 1 | R37C16[1][A] | g_sound.u_evt_merge/cnt_next_2_s/COUT
13.851 | 0.000 | tNET | RR | 2 | R37C16[1][B] | g_sound.u_evt_merge/cnt_next_3_s/CIN
13.896 | 0.045 | tINS | RR | 1 | R37C16[1][B] | g_sound.u_evt_merge/cnt_next_3_s/COUT
13.896 | 0.000 | tNET | RR | 2 | R37C16[2][A] | g_sound.u_evt_merge/cnt_next_4_s/CIN
13.941 | 0.045 | tINS | RR | 1 | R37C16[2][A] | g_sound.u_evt_merge/cnt_next_4_s/COUT
13.941 | 0.000 | tNET | RR | 2 | R37C16[2][B] | g_sound.u_evt_merge/cnt_next_5_s/CIN
13.986 | 0.045 | tINS | RR | 1 | R37C16[2][B] | g_sound.u_evt_merge/cnt_next_5_s/COUT
13.986 | 0.000 | tNET | RR | 2 | R37C17[0][A] | g_sound.u_evt_merge/cnt_next_6_s/CIN
14.031 | 0.045 | tINS | RR | 1 | R37C17[0][A] | g_sound.u_evt_merge/cnt_next_6_s/COUT
14.031 | 0.000 | tNET | RR | 2 | R37C17[0][B] | g_sound.u_evt_merge/cnt_next_7_s/CIN
14.298 | 0.267 | tINS | RR | 1 | R37C17[0][B] | g_sound.u_evt_merge/cnt_next_7_s/SUM
14.422 | 0.124 | tNET | RR | 1 | R37C17[3][B] | g_sound.u_evt_merge/n1433_s4/I3
14.869 | 0.448 | tINS | RR | 1 | R37C17[3][B] | g_sound.u_evt_merge/n1433_s4/F
15.011 | 0.142 | tNET | RR | 1 | R37C16[3][A] | g_sound.u_evt_merge/n1433_s3/I2
15.480 | 0.469 | tINS | RR | 1 | R37C16[3][A] | g_sound.u_evt_merge/n1433_s3/F
15.622 | 0.142 | tNET | RR | 1 | R37C15[3][B] | g_sound.u_evt_merge/n1433_s2/I2
16.070 | 0.448 | tINS | RR | 1 | R37C15[3][B] | g_sound.u_evt_merge/n1433_s2/F
16.072 | 0.002 | tNET | RR | 1 | R37C15[2][A] | g_sound.u_evt_merge/n1433_s1/I3
16.546 | 0.474 | tINS | RR | 1 | R37C15[2][A] | g_sound.u_evt_merge/n1433_s1/F
16.858 | 0.313 | tNET | RR | 1 | R37C18[2][B] | g_sound.u_evt_merge/n1433_s0/I3
17.273 | 0.415 | tINS | RR | 38 | R37C18[2][B] | g_sound.u_evt_merge/n1433_s0/F
18.106 | 0.833 | tNET | RR | 1 | R35C6[0][A] | g_sound.u_evt_merge/mem_s3593/I3
18.571 | 0.465 | tINS | RR | 1 | R35C6[0][A] | g_sound.u_evt_merge/mem_s3593/F
18.915 | 0.344 | tNET | RR | 1 | R31C6[1][B] | g_sound.u_evt_merge/mem_s3570/I2
19.379 | 0.465 | tINS | RR | 8 | R31C6[1][B] | g_sound.u_evt_merge/mem_s3570/F
19.953 | 0.574 | tNET | RR | 1 | R31C12[3][B] | g_sound.u_evt_merge/mem_s3512/I2
20.401 | 0.448 | tINS | RR | 70 | R31C12[3][B] | g_sound.u_evt_merge/mem_s3512/F
20.896 | 0.495 | tNET | RR | 1 | R31C9[2][B] | g_sound.u_evt_merge/mem_s3662/I3
21.361 | 0.465 | tINS | RR | 13 | R31C9[2][B] | g_sound.u_evt_merge/mem_s3662/F
21.734 | 0.373 | tNET | RR | 1 | R31C12[3][A] | g_sound.u_evt_merge/mem_s3081/I1
22.182 | 0.448 | tINS | RR | 50 | R31C12[3][A] | g_sound.u_evt_merge/mem_s3081/F
23.741 | 1.559 | tNET | RR | 1 | R33C3[1][A] | g_sound.u_evt_merge/mem_mem_RAMREG_4_G[22]_s0/CE

Data Required Path:

AT | DELAY | TYPE | RF | FANOUT | LOC | NODE
20.000 | 20.000 | | | | | active clock edge time
20.000 | 0.000 | | | | | clk_sys
20.000 | 0.000 | tCL | RR | 1 | IOB117[B] | clk_ibuf/I
21.288 | 1.288 | tINS | RR | 15774 | IOB117[B] | clk_ibuf/O
24.587 | 3.299 | tNET | RR | 1 | R33C3[1][A] | g_sound.u_evt_merge/mem_mem_RAMREG_4_G[22]_s0/CLK
24.307 | -0.280 | tSu | | 1 | R33C3[1][A] | g_sound.u_evt_merge/mem_mem_RAMREG_4_G[22]_s0

Path Statistics:

Clock Skew | 0.008
Setup Relationship | 20.000
Logic Level | 20
Arrival Clock Path Delay | cell: 1.288, 28.136%; route: 3.291, 71.864%
Arrival Data Path Delay | cell: 7.791, 40.656%; route: 11.027, 57.547%; tC2Q: 0.344, 1.797%
Required Clock Path Delay | cell: 1.288, 28.084%; route: 3.299, 71.916%

### Path19

Path Summary:

Slack | 0.582
Data Arrival Time | 20.151
Data Required Time | 20.733
From | g_sound.u_adc_farm/u_scan0/sample_channel_0_s0
To | g_sound.u_calib1/n840_s
Launch Clk | clk_sys:[R]
Latch Clk | clk_sys:[R]

Data Arrival Path:

AT | DELAY | TYPE | RF | FANOUT | LOC | NODE
0.000 | 0.000 | | | | | active clock edge time
0.000 | 0.000 | | | | | clk_sys
0.000 | 0.000 | tCL | RR | 1 | IOB117[B] | clk_ibuf/I
1.288 | 1.288 | tINS | RR | 15774 | IOB117[B] | clk_ibuf/O
4.142 | 2.854 | tNET | RR | 1 | R8C82[0][B] | g_sound.u_adc_farm/u_scan0/sample_channel_0_s0/CLK
4.473 | 0.331 | tC2Q | RF | 141 | R8C82[0][B] | g_sound.u_adc_farm/u_scan0/sample_channel_0_s0/Q
10.513 | 6.040 | tNET | FF | 1 | R31C20[0][B] | g_sound.u_calib1/span_r_RAMOUT_28_G[0]_s0/S0
10.740 | 0.227 | tINS | FR | 3 | R31C20[0][B] | g_sound.u_calib1/span_r_RAMOUT_28_G[0]_s0/O
11.774 | 1.034 | tNET | RR | 1 | R30C39[2][A] | g_sound.u_calib1/dclamp_9_s19/I1
12.248 | 0.474 | tINS | RR | 1 | R30C39[2][A] | g_sound.u_calib1/dclamp_9_s19/F
12.250 | 0.002 | tNET | RR | 1 | R30C39[1][B] | g_sound.u_calib1/dclamp_9_s16/I3
12.665 | 0.415 | tINS | RR | 1 | R30C39[1][B] | g_sound.u_calib1/dclamp_9_s16/F
12.807 | 0.142 | tNET | RR | 1 | R30C38[1][A] | g_sound.u_calib1/dclamp_9_s7/I2
13.043 | 0.236 | tINS | RR | 1 | R30C38[1][A] | g_sound.u_calib1/dclamp_9_s7/F
13.828 | 0.785 | tNET | RR | 1 | R30C26[0][B] | g_sound.u_calib1/dclamp_9_s4/I3
14.302 | 0.474 | tINS | RR | 13 | R30C26[0][B] | g_sound.u_calib1/dclamp_9_s4/F
15.158 | 0.856 | tNET | RR | 1 | R30C44[2][B] | g_sound.u_calib1/dclamp_7_s5/I3
15.623 | 0.465 | tINS | RR | 1 | R30C44[2][B] | g_sound.u_calib1/dclamp_7_s5/F
15.625 | 0.002 | tNET | RR | 1 | R30C44[3][A] | g_sound.u_calib1/dclamp_7_s4/I2
16.073 | 0.448 | tINS | RR | 1 | R30C44[3][A] | g_sound.u_calib1/dclamp_7_s4/F
16.214 | 0.142 | tNET | RR | 1 | R30C43[1][A] | g_sound.u_calib1/dclamp_7_s3/I1
16.451 | 0.236 | tINS | RR | 1 | R30C43[1][A] | g_sound.u_calib1/dclamp_7_s3/F
16.453 | 0.002 | tNET | RR | 1 | R30C43[3][B] | g_sound.u_calib1/dclamp_7_s2/I2
16.714 | 0.261 | tINS | RF | 8 | R30C43[3][B] | g_sound.u_calib1/dclamp_7_s2/F
17.074 | 0.360 | tNET | FF | 1 | R30C40[0][B] | g_sound.u_calib1/dclamp_2_s0/I2
17.310 | 0.236 | tINS | FR | 1 | R30C40[0][B] | g_sound.u_calib1/dclamp_2_s0/F
20.151 | 2.841 | tNET | RR | 1 | DSP_R28[6] | g_sound.u_calib1/n840_s/A[2]

Data Required Path:

AT | DELAY | TYPE | RF | FANOUT | LOC | NODE
20.000 | 20.000 | | | | | active clock edge time
20.000 | 0.000 | | | | | clk_sys
20.000 | 0.000 | tCL | RR | 1 | IOB117[B] | clk_ibuf/I
21.288 | 1.288 | tINS | RR | 15774 | IOB117[B] | clk_ibuf/O
24.133 | 2.845 | tNET | RR | 1 | DSP_R28[6] | g_sound.u_calib1/n840_s/CLK[0]
20.733 | -3.401 | tSu | | 1 | DSP_R28[6] | g_sound.u_calib1/n840_s

Path Statistics:

Clock Skew | -0.008
Setup Relationship | 20.000
Logic Level | 11
Arrival Clock Path Delay | cell: 1.288, 31.105%; route: 2.854, 68.895%
Arrival Data Path Delay | cell: 3.472, 21.687%; route: 12.206, 76.247%; tC2Q: 0.331, 2.066%
Required Clock Path Delay | cell: 1.288, 31.169%; route: 2.845, 68.831%

### Path20

Path Summary:

Slack | 0.588
Data Arrival Time | 23.711
Data Required Time | 24.299
From | g_sound.u_evt_merge/cnt_q_0_s0
To | g_sound.u_evt_merge/mem_mem_RAMREG_4_G[48]_s0
Launch Clk | clk_sys:[R]
Latch Clk | clk_sys:[R]

Data Arrival Path:

AT | DELAY | TYPE | RF | FANOUT | LOC | NODE
0.000 | 0.000 | | | | | active clock edge time
0.000 | 0.000 | | | | | clk_sys
0.000 | 0.000 | tCL | RR | 1 | IOB117[B] | clk_ibuf/I
1.288 | 1.288 | tINS | RR | 15774 | IOB117[B] | clk_ibuf/O
4.579 | 3.291 | tNET | RR | 1 | R37C18[2][A] | g_sound.u_evt_merge/cnt_q_0_s0/CLK
4.923 | 0.344 | tC2Q | RR | 6 | R37C18[2][A] | g_sound.u_evt_merge/cnt_q_0_s0/Q
5.276 | 0.353 | tNET | RR | 1 | R33C18[0][A] | g_sound.u_evt_merge/cnt_after_pop_5_s1/I0
5.750 | 0.474 | tINS | RR | 5 | R33C18[0][A] | g_sound.u_evt_merge/cnt_after_pop_5_s1/F
6.067 | 0.317 | tNET | RR | 1 | R33C16[1][B] | g_sound.u_evt_merge/cnt_after_pop_8_s1/I3
6.541 | 0.474 | tINS | RR | 5 | R33C16[1][B] | g_sound.u_evt_merge/cnt_after_pop_8_s1/F
6.692 | 0.151 | tNET | RR | 1 | R33C17[1][A] | g_sound.u_evt_merge/cnt_after_pop_11_s1/I3
7.107 | 0.415 | tINS | RR | 5 | R33C17[1][A] | g_sound.u_evt_merge/cnt_after_pop_11_s1/F
7.255 | 0.149 | tNET | RR | 1 | R33C18[2][A] | g_sound.u_evt_merge/cnt_after_pop_13_s2/I3
7.670 | 0.415 | tINS | RR | 5 | R33C18[2][A] | g_sound.u_evt_merge/cnt_after_pop_13_s2/F
8.145 | 0.475 | tNET | RR | 1 | R33C15[0][A] | g_sound.u_evt_merge/pop_now_s2/I3
8.381 | 0.236 | tINS | RR | 89 | R33C15[0][A] | g_sound.u_evt_merge/pop_now_s2/F
12.717 | 4.336 | tNET | RR | 1 | R34C16[0][B] | g_sound.u_evt_merge/cnt_after_pop_1_s0/I1
12.953 | 0.236 | tINS | RR | 2 | R34C16[0][B] | g_sound.u_evt_merge/cnt_after_pop_1_s0/F
13.300 | 0.346 | tNET | RR | 2 | R37C16[0][B] | g_sound.u_evt_merge/cnt_next_1_s/I0
13.806 | 0.506 | tINS | RF | 1 | R37C16[0][B] | g_sound.u_evt_merge/cnt_next_1_s/COUT
13.806 | 0.000 | tNET | FF | 2 | R37C16[1][A] | g_sound.u_evt_merge/cnt_next_2_s/CIN
13.851 | 0.045 | tINS | FR | 1 | R37C16[1][A] | g_sound.u_evt_merge/cnt_next_2_s/COUT
13.851 | 0.000 | tNET | RR | 2 | R37C16[1][B] | g_sound.u_evt_merge/cnt_next_3_s/CIN
13.896 | 0.045 | tINS | RR | 1 | R37C16[1][B] | g_sound.u_evt_merge/cnt_next_3_s/COUT
13.896 | 0.000 | tNET | RR | 2 | R37C16[2][A] | g_sound.u_evt_merge/cnt_next_4_s/CIN
13.941 | 0.045 | tINS | RR | 1 | R37C16[2][A] | g_sound.u_evt_merge/cnt_next_4_s/COUT
13.941 | 0.000 | tNET | RR | 2 | R37C16[2][B] | g_sound.u_evt_merge/cnt_next_5_s/CIN
13.986 | 0.045 | tINS | RR | 1 | R37C16[2][B] | g_sound.u_evt_merge/cnt_next_5_s/COUT
13.986 | 0.000 | tNET | RR | 2 | R37C17[0][A] | g_sound.u_evt_merge/cnt_next_6_s/CIN
14.031 | 0.045 | tINS | RR | 1 | R37C17[0][A] | g_sound.u_evt_merge/cnt_next_6_s/COUT
14.031 | 0.000 | tNET | RR | 2 | R37C17[0][B] | g_sound.u_evt_merge/cnt_next_7_s/CIN
14.298 | 0.267 | tINS | RR | 1 | R37C17[0][B] | g_sound.u_evt_merge/cnt_next_7_s/SUM
14.422 | 0.124 | tNET | RR | 1 | R37C17[3][B] | g_sound.u_evt_merge/n1433_s4/I3
14.869 | 0.448 | tINS | RR | 1 | R37C17[3][B] | g_sound.u_evt_merge/n1433_s4/F
15.011 | 0.142 | tNET | RR | 1 | R37C16[3][A] | g_sound.u_evt_merge/n1433_s3/I2
15.480 | 0.469 | tINS | RR | 1 | R37C16[3][A] | g_sound.u_evt_merge/n1433_s3/F
15.622 | 0.142 | tNET | RR | 1 | R37C15[3][B] | g_sound.u_evt_merge/n1433_s2/I2
16.070 | 0.448 | tINS | RR | 1 | R37C15[3][B] | g_sound.u_evt_merge/n1433_s2/F
16.072 | 0.002 | tNET | RR | 1 | R37C15[2][A] | g_sound.u_evt_merge/n1433_s1/I3
16.546 | 0.474 | tINS | RR | 1 | R37C15[2][A] | g_sound.u_evt_merge/n1433_s1/F
16.858 | 0.313 | tNET | RR | 1 | R37C18[2][B] | g_sound.u_evt_merge/n1433_s0/I3
17.273 | 0.415 | tINS | RR | 38 | R37C18[2][B] | g_sound.u_evt_merge/n1433_s0/F
18.106 | 0.833 | tNET | RR | 1 | R35C6[0][A] | g_sound.u_evt_merge/mem_s3593/I3
18.571 | 0.465 | tINS | RR | 1 | R35C6[0][A] | g_sound.u_evt_merge/mem_s3593/F
18.915 | 0.344 | tNET | RR | 1 | R31C6[1][B] | g_sound.u_evt_merge/mem_s3570/I2
19.379 | 0.465 | tINS | RR | 8 | R31C6[1][B] | g_sound.u_evt_merge/mem_s3570/F
19.953 | 0.574 | tNET | RR | 1 | R31C12[3][B] | g_sound.u_evt_merge/mem_s3512/I2
20.401 | 0.448 | tINS | RR | 70 | R31C12[3][B] | g_sound.u_evt_merge/mem_s3512/F
20.896 | 0.495 | tNET | RR | 1 | R31C9[2][B] | g_sound.u_evt_merge/mem_s3662/I3
21.361 | 0.465 | tINS | RR | 13 | R31C9[2][B] | g_sound.u_evt_merge/mem_s3662/F
21.734 | 0.373 | tNET | RR | 1 | R31C12[3][A] | g_sound.u_evt_merge/mem_s3081/I1
22.182 | 0.448 | tINS | RR | 50 | R31C12[3][A] | g_sound.u_evt_merge/mem_s3081/F
23.711 | 1.529 | tNET | RR | 1 | R31C18[0][B] | g_sound.u_evt_merge/mem_mem_RAMREG_4_G[48]_s0/CE

Data Required Path:

AT | DELAY | TYPE | RF | FANOUT | LOC | NODE
20.000 | 20.000 | | | | | active clock edge time
20.000 | 0.000 | | | | | clk_sys
20.000 | 0.000 | tCL | RR | 1 | IOB117[B] | clk_ibuf/I
21.288 | 1.288 | tINS | RR | 15774 | IOB117[B] | clk_ibuf/O
24.579 | 3.291 | tNET | RR | 1 | R31C18[0][B] | g_sound.u_evt_merge/mem_mem_RAMREG_4_G[48]_s0/CLK
24.299 | -0.280 | tSu | | 1 | R31C18[0][B] | g_sound.u_evt_merge/mem_mem_RAMREG_4_G[48]_s0

Path Statistics:

Clock Skew | 0.000
Setup Relationship | 20.000
Logic Level | 20
Arrival Clock Path Delay | cell: 1.288, 28.136%; route: 3.291, 71.864%
Arrival Data Path Delay | cell: 7.791, 40.720%; route: 10.997, 57.481%; tC2Q: 0.344, 1.799%
Required Clock Path Delay | cell: 1.288, 28.136%; route: 3.291, 71.864%

### Path21

Path Summary:

Slack | 0.588
Data Arrival Time | 23.711
Data Required Time | 24.299
From | g_sound.u_evt_merge/cnt_q_0_s0
To | g_sound.u_evt_merge/mem_mem_RAMREG_4_G[47]_s0
Launch Clk | clk_sys:[R]
Latch Clk | clk_sys:[R]

Data Arrival Path:

AT | DELAY | TYPE | RF | FANOUT | LOC | NODE
0.000 | 0.000 | | | | | active clock edge time
0.000 | 0.000 | | | | | clk_sys
0.000 | 0.000 | tCL | RR | 1 | IOB117[B] | clk_ibuf/I
1.288 | 1.288 | tINS | RR | 15774 | IOB117[B] | clk_ibuf/O
4.579 | 3.291 | tNET | RR | 1 | R37C18[2][A] | g_sound.u_evt_merge/cnt_q_0_s0/CLK
4.923 | 0.344 | tC2Q | RR | 6 | R37C18[2][A] | g_sound.u_evt_merge/cnt_q_0_s0/Q
5.276 | 0.353 | tNET | RR | 1 | R33C18[0][A] | g_sound.u_evt_merge/cnt_after_pop_5_s1/I0
5.750 | 0.474 | tINS | RR | 5 | R33C18[0][A] | g_sound.u_evt_merge/cnt_after_pop_5_s1/F
6.067 | 0.317 | tNET | RR | 1 | R33C16[1][B] | g_sound.u_evt_merge/cnt_after_pop_8_s1/I3
6.541 | 0.474 | tINS | RR | 5 | R33C16[1][B] | g_sound.u_evt_merge/cnt_after_pop_8_s1/F
6.692 | 0.151 | tNET | RR | 1 | R33C17[1][A] | g_sound.u_evt_merge/cnt_after_pop_11_s1/I3
7.107 | 0.415 | tINS | RR | 5 | R33C17[1][A] | g_sound.u_evt_merge/cnt_after_pop_11_s1/F
7.255 | 0.149 | tNET | RR | 1 | R33C18[2][A] | g_sound.u_evt_merge/cnt_after_pop_13_s2/I3
7.670 | 0.415 | tINS | RR | 5 | R33C18[2][A] | g_sound.u_evt_merge/cnt_after_pop_13_s2/F
8.145 | 0.475 | tNET | RR | 1 | R33C15[0][A] | g_sound.u_evt_merge/pop_now_s2/I3
8.381 | 0.236 | tINS | RR | 89 | R33C15[0][A] | g_sound.u_evt_merge/pop_now_s2/F
12.717 | 4.336 | tNET | RR | 1 | R34C16[0][B] | g_sound.u_evt_merge/cnt_after_pop_1_s0/I1
12.953 | 0.236 | tINS | RR | 2 | R34C16[0][B] | g_sound.u_evt_merge/cnt_after_pop_1_s0/F
13.300 | 0.346 | tNET | RR | 2 | R37C16[0][B] | g_sound.u_evt_merge/cnt_next_1_s/I0
13.806 | 0.506 | tINS | RF | 1 | R37C16[0][B] | g_sound.u_evt_merge/cnt_next_1_s/COUT
13.806 | 0.000 | tNET | FF | 2 | R37C16[1][A] | g_sound.u_evt_merge/cnt_next_2_s/CIN
13.851 | 0.045 | tINS | FR | 1 | R37C16[1][A] | g_sound.u_evt_merge/cnt_next_2_s/COUT
13.851 | 0.000 | tNET | RR | 2 | R37C16[1][B] | g_sound.u_evt_merge/cnt_next_3_s/CIN
13.896 | 0.045 | tINS | RR | 1 | R37C16[1][B] | g_sound.u_evt_merge/cnt_next_3_s/COUT
13.896 | 0.000 | tNET | RR | 2 | R37C16[2][A] | g_sound.u_evt_merge/cnt_next_4_s/CIN
13.941 | 0.045 | tINS | RR | 1 | R37C16[2][A] | g_sound.u_evt_merge/cnt_next_4_s/COUT
13.941 | 0.000 | tNET | RR | 2 | R37C16[2][B] | g_sound.u_evt_merge/cnt_next_5_s/CIN
13.986 | 0.045 | tINS | RR | 1 | R37C16[2][B] | g_sound.u_evt_merge/cnt_next_5_s/COUT
13.986 | 0.000 | tNET | RR | 2 | R37C17[0][A] | g_sound.u_evt_merge/cnt_next_6_s/CIN
14.031 | 0.045 | tINS | RR | 1 | R37C17[0][A] | g_sound.u_evt_merge/cnt_next_6_s/COUT
14.031 | 0.000 | tNET | RR | 2 | R37C17[0][B] | g_sound.u_evt_merge/cnt_next_7_s/CIN
14.298 | 0.267 | tINS | RR | 1 | R37C17[0][B] | g_sound.u_evt_merge/cnt_next_7_s/SUM
14.422 | 0.124 | tNET | RR | 1 | R37C17[3][B] | g_sound.u_evt_merge/n1433_s4/I3
14.869 | 0.448 | tINS | RR | 1 | R37C17[3][B] | g_sound.u_evt_merge/n1433_s4/F
15.011 | 0.142 | tNET | RR | 1 | R37C16[3][A] | g_sound.u_evt_merge/n1433_s3/I2
15.480 | 0.469 | tINS | RR | 1 | R37C16[3][A] | g_sound.u_evt_merge/n1433_s3/F
15.622 | 0.142 | tNET | RR | 1 | R37C15[3][B] | g_sound.u_evt_merge/n1433_s2/I2
16.070 | 0.448 | tINS | RR | 1 | R37C15[3][B] | g_sound.u_evt_merge/n1433_s2/F
16.072 | 0.002 | tNET | RR | 1 | R37C15[2][A] | g_sound.u_evt_merge/n1433_s1/I3
16.546 | 0.474 | tINS | RR | 1 | R37C15[2][A] | g_sound.u_evt_merge/n1433_s1/F
16.858 | 0.313 | tNET | RR | 1 | R37C18[2][B] | g_sound.u_evt_merge/n1433_s0/I3
17.273 | 0.415 | tINS | RR | 38 | R37C18[2][B] | g_sound.u_evt_merge/n1433_s0/F
18.106 | 0.833 | tNET | RR | 1 | R35C6[0][A] | g_sound.u_evt_merge/mem_s3593/I3
18.571 | 0.465 | tINS | RR | 1 | R35C6[0][A] | g_sound.u_evt_merge/mem_s3593/F
18.915 | 0.344 | tNET | RR | 1 | R31C6[1][B] | g_sound.u_evt_merge/mem_s3570/I2
19.379 | 0.465 | tINS | RR | 8 | R31C6[1][B] | g_sound.u_evt_merge/mem_s3570/F
19.953 | 0.574 | tNET | RR | 1 | R31C12[3][B] | g_sound.u_evt_merge/mem_s3512/I2
20.401 | 0.448 | tINS | RR | 70 | R31C12[3][B] | g_sound.u_evt_merge/mem_s3512/F
20.896 | 0.495 | tNET | RR | 1 | R31C9[2][B] | g_sound.u_evt_merge/mem_s3662/I3
21.361 | 0.465 | tINS | RR | 13 | R31C9[2][B] | g_sound.u_evt_merge/mem_s3662/F
21.734 | 0.373 | tNET | RR | 1 | R31C12[3][A] | g_sound.u_evt_merge/mem_s3081/I1
22.182 | 0.448 | tINS | RR | 50 | R31C12[3][A] | g_sound.u_evt_merge/mem_s3081/F
23.711 | 1.529 | tNET | RR | 1 | R31C18[1][A] | g_sound.u_evt_merge/mem_mem_RAMREG_4_G[47]_s0/CE

Data Required Path:

AT | DELAY | TYPE | RF | FANOUT | LOC | NODE
20.000 | 20.000 | | | | | active clock edge time
20.000 | 0.000 | | | | | clk_sys
20.000 | 0.000 | tCL | RR | 1 | IOB117[B] | clk_ibuf/I
21.288 | 1.288 | tINS | RR | 15774 | IOB117[B] | clk_ibuf/O
24.579 | 3.291 | tNET | RR | 1 | R31C18[1][A] | g_sound.u_evt_merge/mem_mem_RAMREG_4_G[47]_s0/CLK
24.299 | -0.280 | tSu | | 1 | R31C18[1][A] | g_sound.u_evt_merge/mem_mem_RAMREG_4_G[47]_s0

Path Statistics:

Clock Skew | 0.000
Setup Relationship | 20.000
Logic Level | 20
Arrival Clock Path Delay | cell: 1.288, 28.136%; route: 3.291, 71.864%
Arrival Data Path Delay | cell: 7.791, 40.720%; route: 10.997, 57.481%; tC2Q: 0.344, 1.799%
Required Clock Path Delay | cell: 1.288, 28.136%; route: 3.291, 71.864%

### Path22

Path Summary:

Slack | 0.588
Data Arrival Time | 23.711
Data Required Time | 24.299
From | g_sound.u_evt_merge/cnt_q_0_s0
To | g_sound.u_evt_merge/mem_mem_RAMREG_4_G[46]_s0
Launch Clk | clk_sys:[R]
Latch Clk | clk_sys:[R]

Data Arrival Path:

AT | DELAY | TYPE | RF | FANOUT | LOC | NODE
0.000 | 0.000 | | | | | active clock edge time
0.000 | 0.000 | | | | | clk_sys
0.000 | 0.000 | tCL | RR | 1 | IOB117[B] | clk_ibuf/I
1.288 | 1.288 | tINS | RR | 15774 | IOB117[B] | clk_ibuf/O
4.579 | 3.291 | tNET | RR | 1 | R37C18[2][A] | g_sound.u_evt_merge/cnt_q_0_s0/CLK
4.923 | 0.344 | tC2Q | RR | 6 | R37C18[2][A] | g_sound.u_evt_merge/cnt_q_0_s0/Q
5.276 | 0.353 | tNET | RR | 1 | R33C18[0][A] | g_sound.u_evt_merge/cnt_after_pop_5_s1/I0
5.750 | 0.474 | tINS | RR | 5 | R33C18[0][A] | g_sound.u_evt_merge/cnt_after_pop_5_s1/F
6.067 | 0.317 | tNET | RR | 1 | R33C16[1][B] | g_sound.u_evt_merge/cnt_after_pop_8_s1/I3
6.541 | 0.474 | tINS | RR | 5 | R33C16[1][B] | g_sound.u_evt_merge/cnt_after_pop_8_s1/F
6.692 | 0.151 | tNET | RR | 1 | R33C17[1][A] | g_sound.u_evt_merge/cnt_after_pop_11_s1/I3
7.107 | 0.415 | tINS | RR | 5 | R33C17[1][A] | g_sound.u_evt_merge/cnt_after_pop_11_s1/F
7.255 | 0.149 | tNET | RR | 1 | R33C18[2][A] | g_sound.u_evt_merge/cnt_after_pop_13_s2/I3
7.670 | 0.415 | tINS | RR | 5 | R33C18[2][A] | g_sound.u_evt_merge/cnt_after_pop_13_s2/F
8.145 | 0.475 | tNET | RR | 1 | R33C15[0][A] | g_sound.u_evt_merge/pop_now_s2/I3
8.381 | 0.236 | tINS | RR | 89 | R33C15[0][A] | g_sound.u_evt_merge/pop_now_s2/F
12.717 | 4.336 | tNET | RR | 1 | R34C16[0][B] | g_sound.u_evt_merge/cnt_after_pop_1_s0/I1
12.953 | 0.236 | tINS | RR | 2 | R34C16[0][B] | g_sound.u_evt_merge/cnt_after_pop_1_s0/F
13.300 | 0.346 | tNET | RR | 2 | R37C16[0][B] | g_sound.u_evt_merge/cnt_next_1_s/I0
13.806 | 0.506 | tINS | RF | 1 | R37C16[0][B] | g_sound.u_evt_merge/cnt_next_1_s/COUT
13.806 | 0.000 | tNET | FF | 2 | R37C16[1][A] | g_sound.u_evt_merge/cnt_next_2_s/CIN
13.851 | 0.045 | tINS | FR | 1 | R37C16[1][A] | g_sound.u_evt_merge/cnt_next_2_s/COUT
13.851 | 0.000 | tNET | RR | 2 | R37C16[1][B] | g_sound.u_evt_merge/cnt_next_3_s/CIN
13.896 | 0.045 | tINS | RR | 1 | R37C16[1][B] | g_sound.u_evt_merge/cnt_next_3_s/COUT
13.896 | 0.000 | tNET | RR | 2 | R37C16[2][A] | g_sound.u_evt_merge/cnt_next_4_s/CIN
13.941 | 0.045 | tINS | RR | 1 | R37C16[2][A] | g_sound.u_evt_merge/cnt_next_4_s/COUT
13.941 | 0.000 | tNET | RR | 2 | R37C16[2][B] | g_sound.u_evt_merge/cnt_next_5_s/CIN
13.986 | 0.045 | tINS | RR | 1 | R37C16[2][B] | g_sound.u_evt_merge/cnt_next_5_s/COUT
13.986 | 0.000 | tNET | RR | 2 | R37C17[0][A] | g_sound.u_evt_merge/cnt_next_6_s/CIN
14.031 | 0.045 | tINS | RR | 1 | R37C17[0][A] | g_sound.u_evt_merge/cnt_next_6_s/COUT
14.031 | 0.000 | tNET | RR | 2 | R37C17[0][B] | g_sound.u_evt_merge/cnt_next_7_s/CIN
14.298 | 0.267 | tINS | RR | 1 | R37C17[0][B] | g_sound.u_evt_merge/cnt_next_7_s/SUM
14.422 | 0.124 | tNET | RR | 1 | R37C17[3][B] | g_sound.u_evt_merge/n1433_s4/I3
14.869 | 0.448 | tINS | RR | 1 | R37C17[3][B] | g_sound.u_evt_merge/n1433_s4/F
15.011 | 0.142 | tNET | RR | 1 | R37C16[3][A] | g_sound.u_evt_merge/n1433_s3/I2
15.480 | 0.469 | tINS | RR | 1 | R37C16[3][A] | g_sound.u_evt_merge/n1433_s3/F
15.622 | 0.142 | tNET | RR | 1 | R37C15[3][B] | g_sound.u_evt_merge/n1433_s2/I2
16.070 | 0.448 | tINS | RR | 1 | R37C15[3][B] | g_sound.u_evt_merge/n1433_s2/F
16.072 | 0.002 | tNET | RR | 1 | R37C15[2][A] | g_sound.u_evt_merge/n1433_s1/I3
16.546 | 0.474 | tINS | RR | 1 | R37C15[2][A] | g_sound.u_evt_merge/n1433_s1/F
16.858 | 0.313 | tNET | RR | 1 | R37C18[2][B] | g_sound.u_evt_merge/n1433_s0/I3
17.273 | 0.415 | tINS | RR | 38 | R37C18[2][B] | g_sound.u_evt_merge/n1433_s0/F
18.106 | 0.833 | tNET | RR | 1 | R35C6[0][A] | g_sound.u_evt_merge/mem_s3593/I3
18.571 | 0.465 | tINS | RR | 1 | R35C6[0][A] | g_sound.u_evt_merge/mem_s3593/F
18.915 | 0.344 | tNET | RR | 1 | R31C6[1][B] | g_sound.u_evt_merge/mem_s3570/I2
19.379 | 0.465 | tINS | RR | 8 | R31C6[1][B] | g_sound.u_evt_merge/mem_s3570/F
19.953 | 0.574 | tNET | RR | 1 | R31C12[3][B] | g_sound.u_evt_merge/mem_s3512/I2
20.401 | 0.448 | tINS | RR | 70 | R31C12[3][B] | g_sound.u_evt_merge/mem_s3512/F
20.896 | 0.495 | tNET | RR | 1 | R31C9[2][B] | g_sound.u_evt_merge/mem_s3662/I3
21.361 | 0.465 | tINS | RR | 13 | R31C9[2][B] | g_sound.u_evt_merge/mem_s3662/F
21.734 | 0.373 | tNET | RR | 1 | R31C12[3][A] | g_sound.u_evt_merge/mem_s3081/I1
22.182 | 0.448 | tINS | RR | 50 | R31C12[3][A] | g_sound.u_evt_merge/mem_s3081/F
23.711 | 1.529 | tNET | RR | 1 | R31C18[1][B] | g_sound.u_evt_merge/mem_mem_RAMREG_4_G[46]_s0/CE

Data Required Path:

AT | DELAY | TYPE | RF | FANOUT | LOC | NODE
20.000 | 20.000 | | | | | active clock edge time
20.000 | 0.000 | | | | | clk_sys
20.000 | 0.000 | tCL | RR | 1 | IOB117[B] | clk_ibuf/I
21.288 | 1.288 | tINS | RR | 15774 | IOB117[B] | clk_ibuf/O
24.579 | 3.291 | tNET | RR | 1 | R31C18[1][B] | g_sound.u_evt_merge/mem_mem_RAMREG_4_G[46]_s0/CLK
24.299 | -0.280 | tSu | | 1 | R31C18[1][B] | g_sound.u_evt_merge/mem_mem_RAMREG_4_G[46]_s0

Path Statistics:

Clock Skew | 0.000
Setup Relationship | 20.000
Logic Level | 20
Arrival Clock Path Delay | cell: 1.288, 28.136%; route: 3.291, 71.864%
Arrival Data Path Delay | cell: 7.791, 40.720%; route: 10.997, 57.481%; tC2Q: 0.344, 1.799%
Required Clock Path Delay | cell: 1.288, 28.136%; route: 3.291, 71.864%

### Path23

Path Summary:

Slack | 0.588
Data Arrival Time | 23.711
Data Required Time | 24.299
From | g_sound.u_evt_merge/cnt_q_0_s0
To | g_sound.u_evt_merge/mem_mem_RAMREG_4_G[39]_s0
Launch Clk | clk_sys:[R]
Latch Clk | clk_sys:[R]

Data Arrival Path:

AT | DELAY | TYPE | RF | FANOUT | LOC | NODE
0.000 | 0.000 | | | | | active clock edge time
0.000 | 0.000 | | | | | clk_sys
0.000 | 0.000 | tCL | RR | 1 | IOB117[B] | clk_ibuf/I
1.288 | 1.288 | tINS | RR | 15774 | IOB117[B] | clk_ibuf/O
4.579 | 3.291 | tNET | RR | 1 | R37C18[2][A] | g_sound.u_evt_merge/cnt_q_0_s0/CLK
4.923 | 0.344 | tC2Q | RR | 6 | R37C18[2][A] | g_sound.u_evt_merge/cnt_q_0_s0/Q
5.276 | 0.353 | tNET | RR | 1 | R33C18[0][A] | g_sound.u_evt_merge/cnt_after_pop_5_s1/I0
5.750 | 0.474 | tINS | RR | 5 | R33C18[0][A] | g_sound.u_evt_merge/cnt_after_pop_5_s1/F
6.067 | 0.317 | tNET | RR | 1 | R33C16[1][B] | g_sound.u_evt_merge/cnt_after_pop_8_s1/I3
6.541 | 0.474 | tINS | RR | 5 | R33C16[1][B] | g_sound.u_evt_merge/cnt_after_pop_8_s1/F
6.692 | 0.151 | tNET | RR | 1 | R33C17[1][A] | g_sound.u_evt_merge/cnt_after_pop_11_s1/I3
7.107 | 0.415 | tINS | RR | 5 | R33C17[1][A] | g_sound.u_evt_merge/cnt_after_pop_11_s1/F
7.255 | 0.149 | tNET | RR | 1 | R33C18[2][A] | g_sound.u_evt_merge/cnt_after_pop_13_s2/I3
7.670 | 0.415 | tINS | RR | 5 | R33C18[2][A] | g_sound.u_evt_merge/cnt_after_pop_13_s2/F
8.145 | 0.475 | tNET | RR | 1 | R33C15[0][A] | g_sound.u_evt_merge/pop_now_s2/I3
8.381 | 0.236 | tINS | RR | 89 | R33C15[0][A] | g_sound.u_evt_merge/pop_now_s2/F
12.717 | 4.336 | tNET | RR | 1 | R34C16[0][B] | g_sound.u_evt_merge/cnt_after_pop_1_s0/I1
12.953 | 0.236 | tINS | RR | 2 | R34C16[0][B] | g_sound.u_evt_merge/cnt_after_pop_1_s0/F
13.300 | 0.346 | tNET | RR | 2 | R37C16[0][B] | g_sound.u_evt_merge/cnt_next_1_s/I0
13.806 | 0.506 | tINS | RF | 1 | R37C16[0][B] | g_sound.u_evt_merge/cnt_next_1_s/COUT
13.806 | 0.000 | tNET | FF | 2 | R37C16[1][A] | g_sound.u_evt_merge/cnt_next_2_s/CIN
13.851 | 0.045 | tINS | FR | 1 | R37C16[1][A] | g_sound.u_evt_merge/cnt_next_2_s/COUT
13.851 | 0.000 | tNET | RR | 2 | R37C16[1][B] | g_sound.u_evt_merge/cnt_next_3_s/CIN
13.896 | 0.045 | tINS | RR | 1 | R37C16[1][B] | g_sound.u_evt_merge/cnt_next_3_s/COUT
13.896 | 0.000 | tNET | RR | 2 | R37C16[2][A] | g_sound.u_evt_merge/cnt_next_4_s/CIN
13.941 | 0.045 | tINS | RR | 1 | R37C16[2][A] | g_sound.u_evt_merge/cnt_next_4_s/COUT
13.941 | 0.000 | tNET | RR | 2 | R37C16[2][B] | g_sound.u_evt_merge/cnt_next_5_s/CIN
13.986 | 0.045 | tINS | RR | 1 | R37C16[2][B] | g_sound.u_evt_merge/cnt_next_5_s/COUT
13.986 | 0.000 | tNET | RR | 2 | R37C17[0][A] | g_sound.u_evt_merge/cnt_next_6_s/CIN
14.031 | 0.045 | tINS | RR | 1 | R37C17[0][A] | g_sound.u_evt_merge/cnt_next_6_s/COUT
14.031 | 0.000 | tNET | RR | 2 | R37C17[0][B] | g_sound.u_evt_merge/cnt_next_7_s/CIN
14.298 | 0.267 | tINS | RR | 1 | R37C17[0][B] | g_sound.u_evt_merge/cnt_next_7_s/SUM
14.422 | 0.124 | tNET | RR | 1 | R37C17[3][B] | g_sound.u_evt_merge/n1433_s4/I3
14.869 | 0.448 | tINS | RR | 1 | R37C17[3][B] | g_sound.u_evt_merge/n1433_s4/F
15.011 | 0.142 | tNET | RR | 1 | R37C16[3][A] | g_sound.u_evt_merge/n1433_s3/I2
15.480 | 0.469 | tINS | RR | 1 | R37C16[3][A] | g_sound.u_evt_merge/n1433_s3/F
15.622 | 0.142 | tNET | RR | 1 | R37C15[3][B] | g_sound.u_evt_merge/n1433_s2/I2
16.070 | 0.448 | tINS | RR | 1 | R37C15[3][B] | g_sound.u_evt_merge/n1433_s2/F
16.072 | 0.002 | tNET | RR | 1 | R37C15[2][A] | g_sound.u_evt_merge/n1433_s1/I3
16.546 | 0.474 | tINS | RR | 1 | R37C15[2][A] | g_sound.u_evt_merge/n1433_s1/F
16.858 | 0.313 | tNET | RR | 1 | R37C18[2][B] | g_sound.u_evt_merge/n1433_s0/I3
17.273 | 0.415 | tINS | RR | 38 | R37C18[2][B] | g_sound.u_evt_merge/n1433_s0/F
18.106 | 0.833 | tNET | RR | 1 | R35C6[0][A] | g_sound.u_evt_merge/mem_s3593/I3
18.571 | 0.465 | tINS | RR | 1 | R35C6[0][A] | g_sound.u_evt_merge/mem_s3593/F
18.915 | 0.344 | tNET | RR | 1 | R31C6[1][B] | g_sound.u_evt_merge/mem_s3570/I2
19.379 | 0.465 | tINS | RR | 8 | R31C6[1][B] | g_sound.u_evt_merge/mem_s3570/F
19.953 | 0.574 | tNET | RR | 1 | R31C12[3][B] | g_sound.u_evt_merge/mem_s3512/I2
20.401 | 0.448 | tINS | RR | 70 | R31C12[3][B] | g_sound.u_evt_merge/mem_s3512/F
20.896 | 0.495 | tNET | RR | 1 | R31C9[2][B] | g_sound.u_evt_merge/mem_s3662/I3
21.361 | 0.465 | tINS | RR | 13 | R31C9[2][B] | g_sound.u_evt_merge/mem_s3662/F
21.734 | 0.373 | tNET | RR | 1 | R31C12[3][A] | g_sound.u_evt_merge/mem_s3081/I1
22.182 | 0.448 | tINS | RR | 50 | R31C12[3][A] | g_sound.u_evt_merge/mem_s3081/F
23.711 | 1.529 | tNET | RR | 1 | R31C18[0][A] | g_sound.u_evt_merge/mem_mem_RAMREG_4_G[39]_s0/CE

Data Required Path:

AT | DELAY | TYPE | RF | FANOUT | LOC | NODE
20.000 | 20.000 | | | | | active clock edge time
20.000 | 0.000 | | | | | clk_sys
20.000 | 0.000 | tCL | RR | 1 | IOB117[B] | clk_ibuf/I
21.288 | 1.288 | tINS | RR | 15774 | IOB117[B] | clk_ibuf/O
24.579 | 3.291 | tNET | RR | 1 | R31C18[0][A] | g_sound.u_evt_merge/mem_mem_RAMREG_4_G[39]_s0/CLK
24.299 | -0.280 | tSu | | 1 | R31C18[0][A] | g_sound.u_evt_merge/mem_mem_RAMREG_4_G[39]_s0

Path Statistics:

Clock Skew | 0.000
Setup Relationship | 20.000
Logic Level | 20
Arrival Clock Path Delay | cell: 1.288, 28.136%; route: 3.291, 71.864%
Arrival Data Path Delay | cell: 7.791, 40.720%; route: 10.997, 57.481%; tC2Q: 0.344, 1.799%
Required Clock Path Delay | cell: 1.288, 28.136%; route: 3.291, 71.864%

### Path24

Path Summary:

Slack | 0.588
Data Arrival Time | 23.720
Data Required Time | 24.307
From | g_sound.u_evt_merge/cnt_q_0_s0
To | g_sound.u_evt_merge/mem_mem_RAMREG_4_G[44]_s0
Launch Clk | clk_sys:[R]
Latch Clk | clk_sys:[R]

Data Arrival Path:

AT | DELAY | TYPE | RF | FANOUT | LOC | NODE
0.000 | 0.000 | | | | | active clock edge time
0.000 | 0.000 | | | | | clk_sys
0.000 | 0.000 | tCL | RR | 1 | IOB117[B] | clk_ibuf/I
1.288 | 1.288 | tINS | RR | 15774 | IOB117[B] | clk_ibuf/O
4.579 | 3.291 | tNET | RR | 1 | R37C18[2][A] | g_sound.u_evt_merge/cnt_q_0_s0/CLK
4.923 | 0.344 | tC2Q | RR | 6 | R37C18[2][A] | g_sound.u_evt_merge/cnt_q_0_s0/Q
5.276 | 0.353 | tNET | RR | 1 | R33C18[0][A] | g_sound.u_evt_merge/cnt_after_pop_5_s1/I0
5.750 | 0.474 | tINS | RR | 5 | R33C18[0][A] | g_sound.u_evt_merge/cnt_after_pop_5_s1/F
6.067 | 0.317 | tNET | RR | 1 | R33C16[1][B] | g_sound.u_evt_merge/cnt_after_pop_8_s1/I3
6.541 | 0.474 | tINS | RR | 5 | R33C16[1][B] | g_sound.u_evt_merge/cnt_after_pop_8_s1/F
6.692 | 0.151 | tNET | RR | 1 | R33C17[1][A] | g_sound.u_evt_merge/cnt_after_pop_11_s1/I3
7.107 | 0.415 | tINS | RR | 5 | R33C17[1][A] | g_sound.u_evt_merge/cnt_after_pop_11_s1/F
7.255 | 0.149 | tNET | RR | 1 | R33C18[2][A] | g_sound.u_evt_merge/cnt_after_pop_13_s2/I3
7.670 | 0.415 | tINS | RR | 5 | R33C18[2][A] | g_sound.u_evt_merge/cnt_after_pop_13_s2/F
8.145 | 0.475 | tNET | RR | 1 | R33C15[0][A] | g_sound.u_evt_merge/pop_now_s2/I3
8.381 | 0.236 | tINS | RR | 89 | R33C15[0][A] | g_sound.u_evt_merge/pop_now_s2/F
12.717 | 4.336 | tNET | RR | 1 | R34C16[0][B] | g_sound.u_evt_merge/cnt_after_pop_1_s0/I1
12.953 | 0.236 | tINS | RR | 2 | R34C16[0][B] | g_sound.u_evt_merge/cnt_after_pop_1_s0/F
13.300 | 0.346 | tNET | RR | 2 | R37C16[0][B] | g_sound.u_evt_merge/cnt_next_1_s/I0
13.806 | 0.506 | tINS | RF | 1 | R37C16[0][B] | g_sound.u_evt_merge/cnt_next_1_s/COUT
13.806 | 0.000 | tNET | FF | 2 | R37C16[1][A] | g_sound.u_evt_merge/cnt_next_2_s/CIN
13.851 | 0.045 | tINS | FR | 1 | R37C16[1][A] | g_sound.u_evt_merge/cnt_next_2_s/COUT
13.851 | 0.000 | tNET | RR | 2 | R37C16[1][B] | g_sound.u_evt_merge/cnt_next_3_s/CIN
13.896 | 0.045 | tINS | RR | 1 | R37C16[1][B] | g_sound.u_evt_merge/cnt_next_3_s/COUT
13.896 | 0.000 | tNET | RR | 2 | R37C16[2][A] | g_sound.u_evt_merge/cnt_next_4_s/CIN
13.941 | 0.045 | tINS | RR | 1 | R37C16[2][A] | g_sound.u_evt_merge/cnt_next_4_s/COUT
13.941 | 0.000 | tNET | RR | 2 | R37C16[2][B] | g_sound.u_evt_merge/cnt_next_5_s/CIN
13.986 | 0.045 | tINS | RR | 1 | R37C16[2][B] | g_sound.u_evt_merge/cnt_next_5_s/COUT
13.986 | 0.000 | tNET | RR | 2 | R37C17[0][A] | g_sound.u_evt_merge/cnt_next_6_s/CIN
14.031 | 0.045 | tINS | RR | 1 | R37C17[0][A] | g_sound.u_evt_merge/cnt_next_6_s/COUT
14.031 | 0.000 | tNET | RR | 2 | R37C17[0][B] | g_sound.u_evt_merge/cnt_next_7_s/CIN
14.298 | 0.267 | tINS | RR | 1 | R37C17[0][B] | g_sound.u_evt_merge/cnt_next_7_s/SUM
14.422 | 0.124 | tNET | RR | 1 | R37C17[3][B] | g_sound.u_evt_merge/n1433_s4/I3
14.869 | 0.448 | tINS | RR | 1 | R37C17[3][B] | g_sound.u_evt_merge/n1433_s4/F
15.011 | 0.142 | tNET | RR | 1 | R37C16[3][A] | g_sound.u_evt_merge/n1433_s3/I2
15.480 | 0.469 | tINS | RR | 1 | R37C16[3][A] | g_sound.u_evt_merge/n1433_s3/F
15.622 | 0.142 | tNET | RR | 1 | R37C15[3][B] | g_sound.u_evt_merge/n1433_s2/I2
16.070 | 0.448 | tINS | RR | 1 | R37C15[3][B] | g_sound.u_evt_merge/n1433_s2/F
16.072 | 0.002 | tNET | RR | 1 | R37C15[2][A] | g_sound.u_evt_merge/n1433_s1/I3
16.546 | 0.474 | tINS | RR | 1 | R37C15[2][A] | g_sound.u_evt_merge/n1433_s1/F
16.858 | 0.313 | tNET | RR | 1 | R37C18[2][B] | g_sound.u_evt_merge/n1433_s0/I3
17.273 | 0.415 | tINS | RR | 38 | R37C18[2][B] | g_sound.u_evt_merge/n1433_s0/F
18.106 | 0.833 | tNET | RR | 1 | R35C6[0][A] | g_sound.u_evt_merge/mem_s3593/I3
18.571 | 0.465 | tINS | RR | 1 | R35C6[0][A] | g_sound.u_evt_merge/mem_s3593/F
18.915 | 0.344 | tNET | RR | 1 | R31C6[1][B] | g_sound.u_evt_merge/mem_s3570/I2
19.379 | 0.465 | tINS | RR | 8 | R31C6[1][B] | g_sound.u_evt_merge/mem_s3570/F
19.953 | 0.574 | tNET | RR | 1 | R31C12[3][B] | g_sound.u_evt_merge/mem_s3512/I2
20.401 | 0.448 | tINS | RR | 70 | R31C12[3][B] | g_sound.u_evt_merge/mem_s3512/F
20.896 | 0.495 | tNET | RR | 1 | R31C9[2][B] | g_sound.u_evt_merge/mem_s3662/I3
21.361 | 0.465 | tINS | RR | 13 | R31C9[2][B] | g_sound.u_evt_merge/mem_s3662/F
21.734 | 0.373 | tNET | RR | 1 | R31C12[3][A] | g_sound.u_evt_merge/mem_s3081/I1
22.182 | 0.448 | tINS | RR | 50 | R31C12[3][A] | g_sound.u_evt_merge/mem_s3081/F
23.720 | 1.538 | tNET | RR | 1 | R31C19[2][A] | g_sound.u_evt_merge/mem_mem_RAMREG_4_G[44]_s0/CE

Data Required Path:

AT | DELAY | TYPE | RF | FANOUT | LOC | NODE
20.000 | 20.000 | | | | | active clock edge time
20.000 | 0.000 | | | | | clk_sys
20.000 | 0.000 | tCL | RR | 1 | IOB117[B] | clk_ibuf/I
21.288 | 1.288 | tINS | RR | 15774 | IOB117[B] | clk_ibuf/O
24.587 | 3.299 | tNET | RR | 1 | R31C19[2][A] | g_sound.u_evt_merge/mem_mem_RAMREG_4_G[44]_s0/CLK
24.307 | -0.280 | tSu | | 1 | R31C19[2][A] | g_sound.u_evt_merge/mem_mem_RAMREG_4_G[44]_s0

Path Statistics:

Clock Skew | 0.008
Setup Relationship | 20.000
Logic Level | 20
Arrival Clock Path Delay | cell: 1.288, 28.136%; route: 3.291, 71.864%
Arrival Data Path Delay | cell: 7.791, 40.702%; route: 11.006, 57.500%; tC2Q: 0.344, 1.799%
Required Clock Path Delay | cell: 1.288, 28.084%; route: 3.299, 71.916%

### Path25

Path Summary:

Slack | 0.588
Data Arrival Time | 23.720
Data Required Time | 24.307
From | g_sound.u_evt_merge/cnt_q_0_s0
To | g_sound.u_evt_merge/mem_mem_RAMREG_4_G[43]_s0
Launch Clk | clk_sys:[R]
Latch Clk | clk_sys:[R]

Data Arrival Path:

AT | DELAY | TYPE | RF | FANOUT | LOC | NODE
0.000 | 0.000 | | | | | active clock edge time
0.000 | 0.000 | | | | | clk_sys
0.000 | 0.000 | tCL | RR | 1 | IOB117[B] | clk_ibuf/I
1.288 | 1.288 | tINS | RR | 15774 | IOB117[B] | clk_ibuf/O
4.579 | 3.291 | tNET | RR | 1 | R37C18[2][A] | g_sound.u_evt_merge/cnt_q_0_s0/CLK
4.923 | 0.344 | tC2Q | RR | 6 | R37C18[2][A] | g_sound.u_evt_merge/cnt_q_0_s0/Q
5.276 | 0.353 | tNET | RR | 1 | R33C18[0][A] | g_sound.u_evt_merge/cnt_after_pop_5_s1/I0
5.750 | 0.474 | tINS | RR | 5 | R33C18[0][A] | g_sound.u_evt_merge/cnt_after_pop_5_s1/F
6.067 | 0.317 | tNET | RR | 1 | R33C16[1][B] | g_sound.u_evt_merge/cnt_after_pop_8_s1/I3
6.541 | 0.474 | tINS | RR | 5 | R33C16[1][B] | g_sound.u_evt_merge/cnt_after_pop_8_s1/F
6.692 | 0.151 | tNET | RR | 1 | R33C17[1][A] | g_sound.u_evt_merge/cnt_after_pop_11_s1/I3
7.107 | 0.415 | tINS | RR | 5 | R33C17[1][A] | g_sound.u_evt_merge/cnt_after_pop_11_s1/F
7.255 | 0.149 | tNET | RR | 1 | R33C18[2][A] | g_sound.u_evt_merge/cnt_after_pop_13_s2/I3
7.670 | 0.415 | tINS | RR | 5 | R33C18[2][A] | g_sound.u_evt_merge/cnt_after_pop_13_s2/F
8.145 | 0.475 | tNET | RR | 1 | R33C15[0][A] | g_sound.u_evt_merge/pop_now_s2/I3
8.381 | 0.236 | tINS | RR | 89 | R33C15[0][A] | g_sound.u_evt_merge/pop_now_s2/F
12.717 | 4.336 | tNET | RR | 1 | R34C16[0][B] | g_sound.u_evt_merge/cnt_after_pop_1_s0/I1
12.953 | 0.236 | tINS | RR | 2 | R34C16[0][B] | g_sound.u_evt_merge/cnt_after_pop_1_s0/F
13.300 | 0.346 | tNET | RR | 2 | R37C16[0][B] | g_sound.u_evt_merge/cnt_next_1_s/I0
13.806 | 0.506 | tINS | RF | 1 | R37C16[0][B] | g_sound.u_evt_merge/cnt_next_1_s/COUT
13.806 | 0.000 | tNET | FF | 2 | R37C16[1][A] | g_sound.u_evt_merge/cnt_next_2_s/CIN
13.851 | 0.045 | tINS | FR | 1 | R37C16[1][A] | g_sound.u_evt_merge/cnt_next_2_s/COUT
13.851 | 0.000 | tNET | RR | 2 | R37C16[1][B] | g_sound.u_evt_merge/cnt_next_3_s/CIN
13.896 | 0.045 | tINS | RR | 1 | R37C16[1][B] | g_sound.u_evt_merge/cnt_next_3_s/COUT
13.896 | 0.000 | tNET | RR | 2 | R37C16[2][A] | g_sound.u_evt_merge/cnt_next_4_s/CIN
13.941 | 0.045 | tINS | RR | 1 | R37C16[2][A] | g_sound.u_evt_merge/cnt_next_4_s/COUT
13.941 | 0.000 | tNET | RR | 2 | R37C16[2][B] | g_sound.u_evt_merge/cnt_next_5_s/CIN
13.986 | 0.045 | tINS | RR | 1 | R37C16[2][B] | g_sound.u_evt_merge/cnt_next_5_s/COUT
13.986 | 0.000 | tNET | RR | 2 | R37C17[0][A] | g_sound.u_evt_merge/cnt_next_6_s/CIN
14.031 | 0.045 | tINS | RR | 1 | R37C17[0][A] | g_sound.u_evt_merge/cnt_next_6_s/COUT
14.031 | 0.000 | tNET | RR | 2 | R37C17[0][B] | g_sound.u_evt_merge/cnt_next_7_s/CIN
14.298 | 0.267 | tINS | RR | 1 | R37C17[0][B] | g_sound.u_evt_merge/cnt_next_7_s/SUM
14.422 | 0.124 | tNET | RR | 1 | R37C17[3][B] | g_sound.u_evt_merge/n1433_s4/I3
14.869 | 0.448 | tINS | RR | 1 | R37C17[3][B] | g_sound.u_evt_merge/n1433_s4/F
15.011 | 0.142 | tNET | RR | 1 | R37C16[3][A] | g_sound.u_evt_merge/n1433_s3/I2
15.480 | 0.469 | tINS | RR | 1 | R37C16[3][A] | g_sound.u_evt_merge/n1433_s3/F
15.622 | 0.142 | tNET | RR | 1 | R37C15[3][B] | g_sound.u_evt_merge/n1433_s2/I2
16.070 | 0.448 | tINS | RR | 1 | R37C15[3][B] | g_sound.u_evt_merge/n1433_s2/F
16.072 | 0.002 | tNET | RR | 1 | R37C15[2][A] | g_sound.u_evt_merge/n1433_s1/I3
16.546 | 0.474 | tINS | RR | 1 | R37C15[2][A] | g_sound.u_evt_merge/n1433_s1/F
16.858 | 0.313 | tNET | RR | 1 | R37C18[2][B] | g_sound.u_evt_merge/n1433_s0/I3
17.273 | 0.415 | tINS | RR | 38 | R37C18[2][B] | g_sound.u_evt_merge/n1433_s0/F
18.106 | 0.833 | tNET | RR | 1 | R35C6[0][A] | g_sound.u_evt_merge/mem_s3593/I3
18.571 | 0.465 | tINS | RR | 1 | R35C6[0][A] | g_sound.u_evt_merge/mem_s3593/F
18.915 | 0.344 | tNET | RR | 1 | R31C6[1][B] | g_sound.u_evt_merge/mem_s3570/I2
19.379 | 0.465 | tINS | RR | 8 | R31C6[1][B] | g_sound.u_evt_merge/mem_s3570/F
19.953 | 0.574 | tNET | RR | 1 | R31C12[3][B] | g_sound.u_evt_merge/mem_s3512/I2
20.401 | 0.448 | tINS | RR | 70 | R31C12[3][B] | g_sound.u_evt_merge/mem_s3512/F
20.896 | 0.495 | tNET | RR | 1 | R31C9[2][B] | g_sound.u_evt_merge/mem_s3662/I3
21.361 | 0.465 | tINS | RR | 13 | R31C9[2][B] | g_sound.u_evt_merge/mem_s3662/F
21.734 | 0.373 | tNET | RR | 1 | R31C12[3][A] | g_sound.u_evt_merge/mem_s3081/I1
22.182 | 0.448 | tINS | RR | 50 | R31C12[3][A] | g_sound.u_evt_merge/mem_s3081/F
23.720 | 1.538 | tNET | RR | 1 | R31C19[2][B] | g_sound.u_evt_merge/mem_mem_RAMREG_4_G[43]_s0/CE

Data Required Path:

AT | DELAY | TYPE | RF | FANOUT | LOC | NODE
20.000 | 20.000 | | | | | active clock edge time
20.000 | 0.000 | | | | | clk_sys
20.000 | 0.000 | tCL | RR | 1 | IOB117[B] | clk_ibuf/I
21.288 | 1.288 | tINS | RR | 15774 | IOB117[B] | clk_ibuf/O
24.587 | 3.299 | tNET | RR | 1 | R31C19[2][B] | g_sound.u_evt_merge/mem_mem_RAMREG_4_G[43]_s0/CLK
24.307 | -0.280 | tSu | | 1 | R31C19[2][B] | g_sound.u_evt_merge/mem_mem_RAMREG_4_G[43]_s0

Path Statistics:

Clock Skew | 0.008
Setup Relationship | 20.000
Logic Level | 20
Arrival Clock Path Delay | cell: 1.288, 28.136%; route: 3.291, 71.864%
Arrival Data Path Delay | cell: 7.791, 40.702%; route: 11.006, 57.500%; tC2Q: 0.344, 1.799%
Required Clock Path Delay | cell: 1.288, 28.084%; route: 3.299, 71.916%

### Hold Analysis Report

#### Report Command:report_timing -hold -max_paths 25 -max_common_paths 1

### Path1

Path Summary:

Slack | 0.127
Data Arrival Time | 2.446
Data Required Time | 2.319
From | g_sound.u_beat_gen/tick_cnt_o_q_4_s0
To | g_sound.u_drum_gen/tick_at_step_q_4_s0
Launch Clk | clk_sys:[R]
Latch Clk | clk_sys:[R]

Data Arrival Path:

AT | DELAY | TYPE | RF | FANOUT | LOC | NODE
0.000 | 0.000 | | | | | active clock edge time
0.000 | 0.000 | | | | | clk_sys
0.000 | 0.000 | tCL | RR | 1 | IOB117[B] | clk_ibuf/I
0.952 | 0.952 | tINS | RR | 15774 | IOB117[B] | clk_ibuf/O
2.186 | 1.234 | tNET | RR | 1 | R40C14[3][A] | g_sound.u_beat_gen/tick_cnt_o_q_4_s0/CLK
2.316 | 0.130 | tC2Q | RR | 3 | R40C14[3][A] | g_sound.u_beat_gen/tick_cnt_o_q_4_s0/Q
2.446 | 0.130 | tNET | RR | 1 | R36C13[1][A] | g_sound.u_drum_gen/tick_at_step_q_4_s0/D

Data Required Path:

AT | DELAY | TYPE | RF | FANOUT | LOC | NODE
0.000 | 0.000 | | | | | active clock edge time
0.000 | 0.000 | | | | | clk_sys
0.000 | 0.000 | tCL | RR | 1 | IOB117[B] | clk_ibuf/I
0.952 | 0.952 | tINS | RR | 15774 | IOB117[B] | clk_ibuf/O
2.367 | 1.415 | tNET | RR | 1 | R36C13[1][A] | g_sound.u_drum_gen/tick_at_step_q_4_s0/CLK
2.319 | -0.048 | tHld | | 1 | R36C13[1][A] | g_sound.u_drum_gen/tick_at_step_q_4_s0

Path Statistics:

Clock Skew | 0.181
Hold Relationship | 0.000
Logic Level | 1
Arrival Clock Path Delay | cell: 0.952, 43.558%; route: 1.234, 56.442%
Arrival Data Path Delay | cell: 0.000, 0.000%; route: 0.130, 50.173%; tC2Q: 0.130, 49.827%
Required Clock Path Delay | cell: 0.952, 40.230%; route: 1.415, 59.770%

### Path2

Path Summary:

Slack | 0.187
Data Arrival Time | 3.011
Data Required Time | 2.823
From | u_hdmi/u_timing/x_2_s0
To | u_hdmi/u_scope/frame_y_frame_y_0_0_s
Launch Clk | pixel_clk:[R]
Latch Clk | pixel_clk:[R]

Data Arrival Path:

AT | DELAY | TYPE | RF | FANOUT | LOC | NODE
0.000 | 0.000 | | | | | active clock edge time
0.000 | 0.000 | | | | | pixel_clk
2.186 | 2.186 | tCL | RR | 154 | PLL_R[1] | u_hdmi/u_clk/u_pll/CLKOUT1
2.792 | 0.606 | tNET | RR | 1 | R37C79[1][A] | u_hdmi/u_timing/x_2_s0/CLK
2.921 | 0.130 | tC2Q | RR | 7 | R37C79[1][A] | u_hdmi/u_timing/x_2_s0/Q
3.011 | 0.089 | tNET | RR | 1 | BSRAM_R38[16][A] | u_hdmi/u_scope/frame_y_frame_y_0_0_s/ADB[5]

Data Required Path:

AT | DELAY | TYPE | RF | FANOUT | LOC | NODE
0.000 | 0.000 | | | | | active clock edge time
0.000 | 0.000 | | | | | pixel_clk
2.186 | 2.186 | tCL | RR | 154 | PLL_R[1] | u_hdmi/u_clk/u_pll/CLKOUT1
2.792 | 0.606 | tNET | RR | 1 | BSRAM_R38[16][A] | u_hdmi/u_scope/frame_y_frame_y_0_0_s/CLKB
2.823 | 0.032 | tHld | | 1 | BSRAM_R38[16][A] | u_hdmi/u_scope/frame_y_frame_y_0_0_s

Path Statistics:

Clock Skew | 0.000
Hold Relationship | 0.000
Logic Level | 1
Arrival Clock Path Delay | cell: 0.000, 0.000%; route: 0.606, 100.000%
Arrival Data Path Delay | cell: 0.000, 0.000%; route: 0.089, 40.741%; tC2Q: 0.130, 59.259%
Required Clock Path Delay | cell: 0.000, 0.000%; route: 0.606, 100.000%

### Path3

Path Summary:

Slack | 0.193
Data Arrival Time | 2.512
Data Required Time | 2.319
From | g_sound.u_beat_gen/tick_cnt_o_q_7_s0
To | g_sound.u_drum_gen/tick_at_step_q_7_s0
Launch Clk | clk_sys:[R]
Latch Clk | clk_sys:[R]

Data Arrival Path:

AT | DELAY | TYPE | RF | FANOUT | LOC | NODE
0.000 | 0.000 | | | | | active clock edge time
0.000 | 0.000 | | | | | clk_sys
0.000 | 0.000 | tCL | RR | 1 | IOB117[B] | clk_ibuf/I
0.952 | 0.952 | tINS | RR | 15774 | IOB117[B] | clk_ibuf/O
2.190 | 1.237 | tNET | RR | 1 | R39C15[3][A] | g_sound.u_beat_gen/tick_cnt_o_q_7_s0/CLK
2.319 | 0.130 | tC2Q | RR | 3 | R39C15[3][A] | g_sound.u_beat_gen/tick_cnt_o_q_7_s0/Q
2.512 | 0.193 | tNET | RR | 1 | R37C15[3][B] | g_sound.u_drum_gen/tick_at_step_q_7_s0/D

Data Required Path:

AT | DELAY | TYPE | RF | FANOUT | LOC | NODE
0.000 | 0.000 | | | | | active clock edge time
0.000 | 0.000 | | | | | clk_sys
0.000 | 0.000 | tCL | RR | 1 | IOB117[B] | clk_ibuf/I
0.952 | 0.952 | tINS | RR | 15774 | IOB117[B] | clk_ibuf/O
2.367 | 1.415 | tNET | RR | 1 | R37C15[3][B] | g_sound.u_drum_gen/tick_at_step_q_7_s0/CLK
2.319 | -0.048 | tHld | | 1 | R37C15[3][B] | g_sound.u_drum_gen/tick_at_step_q_7_s0

Path Statistics:

Clock Skew | 0.177
Hold Relationship | 0.000
Logic Level | 1
Arrival Clock Path Delay | cell: 0.952, 43.487%; route: 1.237, 56.513%
Arrival Data Path Delay | cell: 0.000, 0.000%; route: 0.193, 59.777%; tC2Q: 0.130, 40.223%
Required Clock Path Delay | cell: 0.952, 40.230%; route: 1.415, 59.770%

### Path4

Path Summary:

Slack | 0.195
Data Arrival Time | 2.511
Data Required Time | 2.316
From | g_sound.u_beat_gen/tick_cnt_o_q_8_s0
To | g_sound.u_drum_gen/tick_at_step_q_8_s0
Launch Clk | clk_sys:[R]
Latch Clk | clk_sys:[R]

Data Arrival Path:

AT | DELAY | TYPE | RF | FANOUT | LOC | NODE
0.000 | 0.000 | | | | | active clock edge time
0.000 | 0.000 | | | | | clk_sys
0.000 | 0.000 | tCL | RR | 1 | IOB117[B] | clk_ibuf/I
0.952 | 0.952 | tINS | RR | 15774 | IOB117[B] | clk_ibuf/O
2.186 | 1.234 | tNET | RR | 1 | R39C14[0][A] | g_sound.u_beat_gen/tick_cnt_o_q_8_s0/CLK
2.316 | 0.130 | tC2Q | RR | 3 | R39C14[0][A] | g_sound.u_beat_gen/tick_cnt_o_q_8_s0/Q
2.511 | 0.195 | tNET | RR | 1 | R37C14[0][B] | g_sound.u_drum_gen/tick_at_step_q_8_s0/D

Data Required Path:

AT | DELAY | TYPE | RF | FANOUT | LOC | NODE
0.000 | 0.000 | | | | | active clock edge time
0.000 | 0.000 | | | | | clk_sys
0.000 | 0.000 | tCL | RR | 1 | IOB117[B] | clk_ibuf/I
0.952 | 0.952 | tINS | RR | 15774 | IOB117[B] | clk_ibuf/O
2.363 | 1.411 | tNET | RR | 1 | R37C14[0][B] | g_sound.u_drum_gen/tick_at_step_q_8_s0/CLK
2.316 | -0.048 | tHld | | 1 | R37C14[0][B] | g_sound.u_drum_gen/tick_at_step_q_8_s0

Path Statistics:

Clock Skew | 0.177
Hold Relationship | 0.000
Logic Level | 1
Arrival Clock Path Delay | cell: 0.952, 43.558%; route: 1.234, 56.442%
Arrival Data Path Delay | cell: 0.000, 0.000%; route: 0.195, 60.111%; tC2Q: 0.130, 39.889%
Required Clock Path Delay | cell: 0.952, 40.291%; route: 1.411, 59.709%

### Path5

Path Summary:

Slack | 0.195
Data Arrival Time | 2.511
Data Required Time | 2.316
From | g_sound.u_beat_gen/tick_cnt_o_q_10_s0
To | g_sound.u_drum_gen/tick_at_step_q_10_s0
Launch Clk | clk_sys:[R]
Latch Clk | clk_sys:[R]

Data Arrival Path:

AT | DELAY | TYPE | RF | FANOUT | LOC | NODE
0.000 | 0.000 | | | | | active clock edge time
0.000 | 0.000 | | | | | clk_sys
0.000 | 0.000 | tCL | RR | 1 | IOB117[B] | clk_ibuf/I
0.952 | 0.952 | tINS | RR | 15774 | IOB117[B] | clk_ibuf/O
2.186 | 1.234 | tNET | RR | 1 | R39C14[0][B] | g_sound.u_beat_gen/tick_cnt_o_q_10_s0/CLK
2.316 | 0.130 | tC2Q | RR | 3 | R39C14[0][B] | g_sound.u_beat_gen/tick_cnt_o_q_10_s0/Q
2.511 | 0.195 | tNET | RR | 1 | R37C14[3][A] | g_sound.u_drum_gen/tick_at_step_q_10_s0/D

Data Required Path:

AT | DELAY | TYPE | RF | FANOUT | LOC | NODE
0.000 | 0.000 | | | | | active clock edge time
0.000 | 0.000 | | | | | clk_sys
0.000 | 0.000 | tCL | RR | 1 | IOB117[B] | clk_ibuf/I
0.952 | 0.952 | tINS | RR | 15774 | IOB117[B] | clk_ibuf/O
2.363 | 1.411 | tNET | RR | 1 | R37C14[3][A] | g_sound.u_drum_gen/tick_at_step_q_10_s0/CLK
2.316 | -0.048 | tHld | | 1 | R37C14[3][A] | g_sound.u_drum_gen/tick_at_step_q_10_s0

Path Statistics:

Clock Skew | 0.177
Hold Relationship | 0.000
Logic Level | 1
Arrival Clock Path Delay | cell: 0.952, 43.558%; route: 1.234, 56.442%
Arrival Data Path Delay | cell: 0.000, 0.000%; route: 0.195, 60.111%; tC2Q: 0.130, 39.889%
Required Clock Path Delay | cell: 0.952, 40.291%; route: 1.411, 59.709%

### Path6

Path Summary:

Slack | 0.195
Data Arrival Time | 2.515
Data Required Time | 2.319
From | g_sound.u_beat_gen/tick_cnt_o_q_15_s0
To | g_sound.u_drum_gen/tick_at_step_q_15_s0
Launch Clk | clk_sys:[R]
Latch Clk | clk_sys:[R]

Data Arrival Path:

AT | DELAY | TYPE | RF | FANOUT | LOC | NODE
0.000 | 0.000 | | | | | active clock edge time
0.000 | 0.000 | | | | | clk_sys
0.000 | 0.000 | tCL | RR | 1 | IOB117[B] | clk_ibuf/I
0.952 | 0.952 | tINS | RR | 15774 | IOB117[B] | clk_ibuf/O
2.190 | 1.237 | tNET | RR | 1 | R39C15[3][B] | g_sound.u_beat_gen/tick_cnt_o_q_15_s0/CLK
2.319 | 0.130 | tC2Q | RR | 3 | R39C15[3][B] | g_sound.u_beat_gen/tick_cnt_o_q_15_s0/Q
2.515 | 0.195 | tNET | RR | 1 | R37C15[0][B] | g_sound.u_drum_gen/tick_at_step_q_15_s0/D

Data Required Path:

AT | DELAY | TYPE | RF | FANOUT | LOC | NODE
0.000 | 0.000 | | | | | active clock edge time
0.000 | 0.000 | | | | | clk_sys
0.000 | 0.000 | tCL | RR | 1 | IOB117[B] | clk_ibuf/I
0.952 | 0.952 | tINS | RR | 15774 | IOB117[B] | clk_ibuf/O
2.367 | 1.415 | tNET | RR | 1 | R37C15[0][B] | g_sound.u_drum_gen/tick_at_step_q_15_s0/CLK
2.319 | -0.048 | tHld | | 1 | R37C15[0][B] | g_sound.u_drum_gen/tick_at_step_q_15_s0

Path Statistics:

Clock Skew | 0.177
Hold Relationship | 0.000
Logic Level | 1
Arrival Clock Path Delay | cell: 0.952, 43.487%; route: 1.237, 56.513%
Arrival Data Path Delay | cell: 0.000, 0.000%; route: 0.195, 60.111%; tC2Q: 0.130, 39.889%
Required Clock Path Delay | cell: 0.952, 40.230%; route: 1.415, 59.770%

### Path7

Path Summary:

Slack | 0.197
Data Arrival Time | 2.516
Data Required Time | 2.319
From | g_sound.u_beat_gen/tick_cnt_o_q_5_s0
To | g_sound.u_drum_gen/tick_at_step_q_5_s0
Launch Clk | clk_sys:[R]
Latch Clk | clk_sys:[R]

Data Arrival Path:

AT | DELAY | TYPE | RF | FANOUT | LOC | NODE
0.000 | 0.000 | | | | | active clock edge time
0.000 | 0.000 | | | | | clk_sys
0.000 | 0.000 | tCL | RR | 1 | IOB117[B] | clk_ibuf/I
0.952 | 0.952 | tINS | RR | 15774 | IOB117[B] | clk_ibuf/O
2.190 | 1.237 | tNET | RR | 1 | R39C15[2][B] | g_sound.u_beat_gen/tick_cnt_o_q_5_s0/CLK
2.319 | 0.130 | tC2Q | RR | 3 | R39C15[2][B] | g_sound.u_beat_gen/tick_cnt_o_q_5_s0/Q
2.516 | 0.197 | tNET | RR | 1 | R37C15[2][B] | g_sound.u_drum_gen/tick_at_step_q_5_s0/D

Data Required Path:

AT | DELAY | TYPE | RF | FANOUT | LOC | NODE
0.000 | 0.000 | | | | | active clock edge time
0.000 | 0.000 | | | | | clk_sys
0.000 | 0.000 | tCL | RR | 1 | IOB117[B] | clk_ibuf/I
0.952 | 0.952 | tINS | RR | 15774 | IOB117[B] | clk_ibuf/O
2.367 | 1.415 | tNET | RR | 1 | R37C15[2][B] | g_sound.u_drum_gen/tick_at_step_q_5_s0/CLK
2.319 | -0.048 | tHld | | 1 | R37C15[2][B] | g_sound.u_drum_gen/tick_at_step_q_5_s0

Path Statistics:

Clock Skew | 0.177
Hold Relationship | 0.000
Logic Level | 1
Arrival Clock Path Delay | cell: 0.952, 43.487%; route: 1.237, 56.513%
Arrival Data Path Delay | cell: 0.000, 0.000%; route: 0.197, 60.331%; tC2Q: 0.130, 39.669%
Required Clock Path Delay | cell: 0.952, 40.230%; route: 1.415, 59.770%

### Path8

Path Summary:

Slack | 0.198
Data Arrival Time | 2.517
Data Required Time | 2.319
From | g_sound.u_beat_gen/tick_cnt_o_q_13_s0
To | g_sound.u_drum_gen/tick_at_step_q_13_s0
Launch Clk | clk_sys:[R]
Latch Clk | clk_sys:[R]

Data Arrival Path:

AT | DELAY | TYPE | RF | FANOUT | LOC | NODE
0.000 | 0.000 | | | | | active clock edge time
0.000 | 0.000 | | | | | clk_sys
0.000 | 0.000 | tCL | RR | 1 | IOB117[B] | clk_ibuf/I
0.952 | 0.952 | tINS | RR | 15774 | IOB117[B] | clk_ibuf/O
2.190 | 1.237 | tNET | RR | 1 | R41C13[3][B] | g_sound.u_beat_gen/tick_cnt_o_q_13_s0/CLK
2.319 | 0.130 | tC2Q | RR | 3 | R41C13[3][B] | g_sound.u_beat_gen/tick_cnt_o_q_13_s0/Q
2.517 | 0.198 | tNET | RR | 1 | R37C15[2][A] | g_sound.u_drum_gen/tick_at_step_q_13_s0/D

Data Required Path:

AT | DELAY | TYPE | RF | FANOUT | LOC | NODE
0.000 | 0.000 | | | | | active clock edge time
0.000 | 0.000 | | | | | clk_sys
0.000 | 0.000 | tCL | RR | 1 | IOB117[B] | clk_ibuf/I
0.952 | 0.952 | tINS | RR | 15774 | IOB117[B] | clk_ibuf/O
2.367 | 1.415 | tNET | RR | 1 | R37C15[2][A] | g_sound.u_drum_gen/tick_at_step_q_13_s0/CLK
2.319 | -0.048 | tHld | | 1 | R37C15[2][A] | g_sound.u_drum_gen/tick_at_step_q_13_s0

Path Statistics:

Clock Skew | 0.177
Hold Relationship | 0.000
Logic Level | 1
Arrival Clock Path Delay | cell: 0.952, 43.487%; route: 1.237, 56.513%
Arrival Data Path Delay | cell: 0.000, 0.000%; route: 0.198, 60.440%; tC2Q: 0.130, 39.560%
Required Clock Path Delay | cell: 0.952, 40.230%; route: 1.415, 59.770%

### Path9

Path Summary:

Slack | 0.205
Data Arrival Time | 2.525
Data Required Time | 2.319
From | g_sound.u_beat_gen/tick_cnt_o_q_6_s0
To | g_sound.u_drum_gen/tick_at_step_q_6_s0
Launch Clk | clk_sys:[R]
Latch Clk | clk_sys:[R]

Data Arrival Path:

AT | DELAY | TYPE | RF | FANOUT | LOC | NODE
0.000 | 0.000 | | | | | active clock edge time
0.000 | 0.000 | | | | | clk_sys
0.000 | 0.000 | tCL | RR | 1 | IOB117[B] | clk_ibuf/I
0.952 | 0.952 | tINS | RR | 15774 | IOB117[B] | clk_ibuf/O
2.186 | 1.234 | tNET | RR | 1 | R40C14[0][B] | g_sound.u_beat_gen/tick_cnt_o_q_6_s0/CLK
2.316 | 0.130 | tC2Q | RR | 3 | R40C14[0][B] | g_sound.u_beat_gen/tick_cnt_o_q_6_s0/Q
2.525 | 0.209 | tNET | RR | 1 | R37C15[3][A] | g_sound.u_drum_gen/tick_at_step_q_6_s0/D

Data Required Path:

AT | DELAY | TYPE | RF | FANOUT | LOC | NODE
0.000 | 0.000 | | | | | active clock edge time
0.000 | 0.000 | | | | | clk_sys
0.000 | 0.000 | tCL | RR | 1 | IOB117[B] | clk_ibuf/I
0.952 | 0.952 | tINS | RR | 15774 | IOB117[B] | clk_ibuf/O
2.367 | 1.415 | tNET | RR | 1 | R37C15[3][A] | g_sound.u_drum_gen/tick_at_step_q_6_s0/CLK
2.319 | -0.048 | tHld | | 1 | R37C15[3][A] | g_sound.u_drum_gen/tick_at_step_q_6_s0

Path Statistics:

Clock Skew | 0.181
Hold Relationship | 0.000
Logic Level | 1
Arrival Clock Path Delay | cell: 0.952, 43.558%; route: 1.234, 56.442%
Arrival Data Path Delay | cell: 0.000, 0.000%; route: 0.209, 61.702%; tC2Q: 0.130, 38.298%
Required Clock Path Delay | cell: 0.952, 40.230%; route: 1.415, 59.770%

### Path10

Path Summary:

Slack | 0.215
Data Arrival Time | 2.534
Data Required Time | 2.319
From | g_sound.u_beat_gen/tick_cnt_o_q_1_s0
To | g_sound.u_drum_gen/tick_at_step_q_1_s0
Launch Clk | clk_sys:[R]
Latch Clk | clk_sys:[R]

Data Arrival Path:

AT | DELAY | TYPE | RF | FANOUT | LOC | NODE
0.000 | 0.000 | | | | | active clock edge time
0.000 | 0.000 | | | | | clk_sys
0.000 | 0.000 | tCL | RR | 1 | IOB117[B] | clk_ibuf/I
0.952 | 0.952 | tINS | RR | 15774 | IOB117[B] | clk_ibuf/O
2.193 | 1.241 | tNET | RR | 1 | R41C12[0][B] | g_sound.u_beat_gen/tick_cnt_o_q_1_s0/CLK
2.323 | 0.130 | tC2Q | RR | 3 | R41C12[0][B] | g_sound.u_beat_gen/tick_cnt_o_q_1_s0/Q
2.534 | 0.211 | tNET | RR | 1 | R36C13[1][B] | g_sound.u_drum_gen/tick_at_step_q_1_s0/D

Data Required Path:

AT | DELAY | TYPE | RF | FANOUT | LOC | NODE
0.000 | 0.000 | | | | | active clock edge time
0.000 | 0.000 | | | | | clk_sys
0.000 | 0.000 | tCL | RR | 1 | IOB117[B] | clk_ibuf/I
0.952 | 0.952 | tINS | RR | 15774 | IOB117[B] | clk_ibuf/O
2.367 | 1.415 | tNET | RR | 1 | R36C13[1][B] | g_sound.u_drum_gen/tick_at_step_q_1_s0/CLK
2.319 | -0.048 | tHld | | 1 | R36C13[1][B] | g_sound.u_drum_gen/tick_at_step_q_1_s0

Path Statistics:

Clock Skew | 0.174
Hold Relationship | 0.000
Logic Level | 1
Arrival Clock Path Delay | cell: 0.952, 43.415%; route: 1.241, 56.585%
Arrival Data Path Delay | cell: 0.000, 0.000%; route: 0.211, 62.005%; tC2Q: 0.130, 37.995%
Required Clock Path Delay | cell: 0.952, 40.230%; route: 1.415, 59.770%

### Path11

Path Summary:

Slack | 0.221
Data Arrival Time | 2.444
Data Required Time | 2.223
From | g_sound.u_note_manager/fifo_wr_0_s3
To | g_sound.u_note_manager/fifo_ax_fifo_ax_0_0_s
Launch Clk | clk_sys:[R]
Latch Clk | clk_sys:[R]

Data Arrival Path:

AT | DELAY | TYPE | RF | FANOUT | LOC | NODE
0.000 | 0.000 | | | | | active clock edge time
0.000 | 0.000 | | | | | clk_sys
0.000 | 0.000 | tCL | RR | 1 | IOB117[B] | clk_ibuf/I
0.952 | 0.952 | tINS | RR | 15774 | IOB117[B] | clk_ibuf/O
2.186 | 1.234 | tNET | RR | 1 | R21C115[3][A] | g_sound.u_note_manager/fifo_wr_0_s3/CLK
2.316 | 0.130 | tC2Q | RR | 6 | R21C115[3][A] | g_sound.u_note_manager/fifo_wr_0_s3/Q
2.444 | 0.129 | tNET | RR | 1 | BSRAM_R19[9][A] | g_sound.u_note_manager/fifo_ax_fifo_ax_0_0_s/ADA[5]

Data Required Path:

AT | DELAY | TYPE | RF | FANOUT | LOC | NODE
0.000 | 0.000 | | | | | active clock edge time
0.000 | 0.000 | | | | | clk_sys
0.000 | 0.000 | tCL | RR | 1 | IOB117[B] | clk_ibuf/I
0.952 | 0.952 | tINS | RR | 15774 | IOB117[B] | clk_ibuf/O
2.190 | 1.237 | tNET | RR | 1 | BSRAM_R19[9][A] | g_sound.u_note_manager/fifo_ax_fifo_ax_0_0_s/CLKA
2.223 | 0.033 | tHld | | 1 | BSRAM_R19[9][A] | g_sound.u_note_manager/fifo_ax_fifo_ax_0_0_s

Path Statistics:

Clock Skew | 0.004
Hold Relationship | 0.000
Logic Level | 1
Arrival Clock Path Delay | cell: 0.952, 43.558%; route: 1.234, 56.442%
Arrival Data Path Delay | cell: 0.000, 0.000%; route: 0.129, 49.826%; tC2Q: 0.130, 50.174%
Required Clock Path Delay | cell: 0.952, 43.487%; route: 1.237, 56.513%

### Path12

Path Summary:

Slack | 0.227
Data Arrival Time | 3.056
Data Required Time | 2.829
From | u_hdmi/u_scope/copy_index_q_6_s0
To | u_hdmi/u_scope/frame_y_frame_y_0_0_s
Launch Clk | pixel_clk:[R]
Latch Clk | pixel_clk:[R]

Data Arrival Path:

AT | DELAY | TYPE | RF | FANOUT | LOC | NODE
0.000 | 0.000 | | | | | active clock edge time
0.000 | 0.000 | | | | | pixel_clk
2.186 | 2.186 | tCL | RR | 154 | PLL_R[1] | u_hdmi/u_clk/u_pll/CLKOUT1
2.795 | 0.609 | tNET | RR | 1 | R44C82[2][A] | u_hdmi/u_scope/copy_index_q_6_s0/CLK
2.925 | 0.130 | tC2Q | RR | 2 | R44C82[2][A] | u_hdmi/u_scope/copy_index_q_6_s0/Q
3.056 | 0.130 | tNET | RR | 1 | BSRAM_R38[16][A] | u_hdmi/u_scope/frame_y_frame_y_0_0_s/ADA[9]

Data Required Path:

AT | DELAY | TYPE | RF | FANOUT | LOC | NODE
0.000 | 0.000 | | | | | active clock edge time
0.000 | 0.000 | | | | | pixel_clk
2.186 | 2.186 | tCL | RR | 154 | PLL_R[1] | u_hdmi/u_clk/u_pll/CLKOUT1
2.795 | 0.609 | tNET | RR | 1 | BSRAM_R38[16][A] | u_hdmi/u_scope/frame_y_frame_y_0_0_s/CLKA
2.829 | 0.033 | tHld | | 1 | BSRAM_R38[16][A] | u_hdmi/u_scope/frame_y_frame_y_0_0_s

Path Statistics:

Clock Skew | 0.000
Hold Relationship | 0.000
Logic Level | 1
Arrival Clock Path Delay | cell: 0.000, 0.000%; route: 0.609, 100.000%
Arrival Data Path Delay | cell: 0.000, 0.000%; route: 0.130, 50.173%; tC2Q: 0.130, 49.827%
Required Clock Path Delay | cell: 0.000, 0.000%; route: 0.609, 100.000%

### Path13

Path Summary:

Slack | 0.234
Data Arrival Time | 2.624
Data Required Time | 2.390
From | g_sound.u_looper/play_inc_o_3_s0
To | g_sound.u_evt_merge/mem_mem_RAMREG_0_G[16]_s0
Launch Clk | clk_sys:[R]
Latch Clk | clk_sys:[R]

Data Arrival Path:

AT | DELAY | TYPE | RF | FANOUT | LOC | NODE
0.000 | 0.000 | | | | | active clock edge time
0.000 | 0.000 | | | | | clk_sys
0.000 | 0.000 | tCL | RR | 1 | IOB117[B] | clk_ibuf/I
0.952 | 0.952 | tINS | RR | 15774 | IOB117[B] | clk_ibuf/O
2.190 | 1.237 | tNET | RR | 1 | R51C3[1][B] | g_sound.u_looper/play_inc_o_3_s0/CLK
2.319 | 0.130 | tC2Q | RR | 8 | R51C3[1][B] | g_sound.u_looper/play_inc_o_3_s0/Q
2.486 | 0.166 | tNET | RR | 1 | R35C5[1][A] | g_sound.u_evt_merge/mem_s2812/I0
2.624 | 0.138 | tINS | RF | 1 | R35C5[1][A] | g_sound.u_evt_merge/mem_s2812/F
2.624 | 0.000 | tNET | FF | 1 | R35C5[1][A] | g_sound.u_evt_merge/mem_mem_RAMREG_0_G[16]_s0/D

Data Required Path:

AT | DELAY | TYPE | RF | FANOUT | LOC | NODE
0.000 | 0.000 | | | | | active clock edge time
0.000 | 0.000 | | | | | clk_sys
0.000 | 0.000 | tCL | RR | 1 | IOB117[B] | clk_ibuf/I
0.952 | 0.952 | tINS | RR | 15774 | IOB117[B] | clk_ibuf/O
2.367 | 1.415 | tNET | RR | 1 | R35C5[1][A] | g_sound.u_evt_merge/mem_mem_RAMREG_0_G[16]_s0/CLK
2.390 | 0.022 | tHld | | 1 | R35C5[1][A] | g_sound.u_evt_merge/mem_mem_RAMREG_0_G[16]_s0

Path Statistics:

Clock Skew | 0.177
Hold Relationship | 0.000
Logic Level | 2
Arrival Clock Path Delay | cell: 0.952, 43.487%; route: 1.237, 56.513%
Arrival Data Path Delay | cell: 0.138, 31.743%; route: 0.166, 38.382%; tC2Q: 0.130, 29.876%
Required Clock Path Delay | cell: 0.952, 40.230%; route: 1.415, 59.770%

### Path14

Path Summary:

Slack | 0.247
Data Arrival Time | 2.460
Data Required Time | 2.212
From | u_i2s_tx/bit_cnt_4_s0
To | u_i2s_tx/bit_cnt_4_s0
Launch Clk | clk_sys:[R]
Latch Clk | clk_sys:[R]

Data Arrival Path:

AT | DELAY | TYPE | RF | FANOUT | LOC | NODE
0.000 | 0.000 | | | | | active clock edge time
0.000 | 0.000 | | | | | clk_sys
0.000 | 0.000 | tCL | RR | 1 | IOB117[B] | clk_ibuf/I
0.952 | 0.952 | tINS | RR | 15774 | IOB117[B] | clk_ibuf/O
2.190 | 1.237 | tNET | RR | 1 | R49C140[1][A] | u_i2s_tx/bit_cnt_4_s0/CLK
2.317 | 0.127 | tC2Q | RF | 3 | R49C140[1][A] | u_i2s_tx/bit_cnt_4_s0/Q
2.322 | 0.005 | tNET | FF | 1 | R49C140[1][A] | u_i2s_tx/n54_s2/I1
2.460 | 0.138 | tINS | FF | 1 | R49C140[1][A] | u_i2s_tx/n54_s2/F
2.460 | 0.000 | tNET | FF | 1 | R49C140[1][A] | u_i2s_tx/bit_cnt_4_s0/D

Data Required Path:

AT | DELAY | TYPE | RF | FANOUT | LOC | NODE
0.000 | 0.000 | | | | | active clock edge time
0.000 | 0.000 | | | | | clk_sys
0.000 | 0.000 | tCL | RR | 1 | IOB117[B] | clk_ibuf/I
0.952 | 0.952 | tINS | RR | 15774 | IOB117[B] | clk_ibuf/O
2.190 | 1.237 | tNET | RR | 1 | R49C140[1][A] | u_i2s_tx/bit_cnt_4_s0/CLK
2.212 | 0.022 | tHld | | 1 | R49C140[1][A] | u_i2s_tx/bit_cnt_4_s0

Path Statistics:

Clock Skew | 0.000
Hold Relationship | 0.000
Logic Level | 2
Arrival Clock Path Delay | cell: 0.952, 43.487%; route: 1.237, 56.513%
Arrival Data Path Delay | cell: 0.138, 51.000%; route: 0.005, 2.000%; tC2Q: 0.127, 47.000%
Required Clock Path Delay | cell: 0.952, 43.487%; route: 1.237, 56.513%

### Path15

Path Summary:

Slack | 0.247
Data Arrival Time | 2.456
Data Required Time | 2.209
From | u_i2s_tx/ch_s0
To | u_i2s_tx/ch_s0
Launch Clk | clk_sys:[R]
Latch Clk | clk_sys:[R]

Data Arrival Path:

AT | DELAY | TYPE | RF | FANOUT | LOC | NODE
0.000 | 0.000 | | | | | active clock edge time
0.000 | 0.000 | | | | | clk_sys
0.000 | 0.000 | tCL | RR | 1 | IOB117[B] | clk_ibuf/I
0.952 | 0.952 | tINS | RR | 15774 | IOB117[B] | clk_ibuf/O
2.186 | 1.234 | tNET | RR | 1 | R68C131[0][A] | u_i2s_tx/ch_s0/CLK
2.313 | 0.127 | tC2Q | RF | 2 | R68C131[0][A] | u_i2s_tx/ch_s0/Q
2.318 | 0.005 | tNET | FF | 1 | R68C131[0][A] | u_i2s_tx/n156_s2/I0
2.456 | 0.138 | tINS | FF | 1 | R68C131[0][A] | u_i2s_tx/n156_s2/F
2.456 | 0.000 | tNET | FF | 1 | R68C131[0][A] | u_i2s_tx/ch_s0/D

Data Required Path:

AT | DELAY | TYPE | RF | FANOUT | LOC | NODE
0.000 | 0.000 | | | | | active clock edge time
0.000 | 0.000 | | | | | clk_sys
0.000 | 0.000 | tCL | RR | 1 | IOB117[B] | clk_ibuf/I
0.952 | 0.952 | tINS | RR | 15774 | IOB117[B] | clk_ibuf/O
2.186 | 1.234 | tNET | RR | 1 | R68C131[0][A] | u_i2s_tx/ch_s0/CLK
2.209 | 0.022 | tHld | | 1 | R68C131[0][A] | u_i2s_tx/ch_s0

Path Statistics:

Clock Skew | 0.000
Hold Relationship | 0.000
Logic Level | 2
Arrival Clock Path Delay | cell: 0.952, 43.558%; route: 1.234, 56.442%
Arrival Data Path Delay | cell: 0.138, 51.000%; route: 0.005, 2.000%; tC2Q: 0.127, 47.000%
Required Clock Path Delay | cell: 0.952, 43.558%; route: 1.234, 56.442%

### Path16

Path Summary:

Slack | 0.247
Data Arrival Time | 2.463
Data Required Time | 2.216
From | g_sound.u_perc_env_bank/gen_perc[4].level_r_0_s0
To | g_sound.u_perc_env_bank/gen_perc[4].level_r_0_s0
Launch Clk | clk_sys:[R]
Latch Clk | clk_sys:[R]

Data Arrival Path:

AT | DELAY | TYPE | RF | FANOUT | LOC | NODE
0.000 | 0.000 | | | | | active clock edge time
0.000 | 0.000 | | | | | clk_sys
0.000 | 0.000 | tCL | RR | 1 | IOB117[B] | clk_ibuf/I
0.952 | 0.952 | tINS | RR | 15774 | IOB117[B] | clk_ibuf/O
2.193 | 1.241 | tNET | RR | 1 | R41C145[0][A] | g_sound.u_perc_env_bank/gen_perc[4].level_r_0_s0/CLK
2.320 | 0.127 | tC2Q | RF | 6 | R41C145[0][A] | g_sound.u_perc_env_bank/gen_perc[4].level_r_0_s0/Q
2.326 | 0.005 | tNET | FF | 1 | R41C145[0][A] | g_sound.u_perc_env_bank/n1574_s2/I1
2.463 | 0.138 | tINS | FF | 1 | R41C145[0][A] | g_sound.u_perc_env_bank/n1574_s2/F
2.463 | 0.000 | tNET | FF | 1 | R41C145[0][A] | g_sound.u_perc_env_bank/gen_perc[4].level_r_0_s0/D

Data Required Path:

AT | DELAY | TYPE | RF | FANOUT | LOC | NODE
0.000 | 0.000 | | | | | active clock edge time
0.000 | 0.000 | | | | | clk_sys
0.000 | 0.000 | tCL | RR | 1 | IOB117[B] | clk_ibuf/I
0.952 | 0.952 | tINS | RR | 15774 | IOB117[B] | clk_ibuf/O
2.193 | 1.241 | tNET | RR | 1 | R41C145[0][A] | g_sound.u_perc_env_bank/gen_perc[4].level_r_0_s0/CLK
2.216 | 0.022 | tHld | | 1 | R41C145[0][A] | g_sound.u_perc_env_bank/gen_perc[4].level_r_0_s0

Path Statistics:

Clock Skew | 0.000
Hold Relationship | 0.000
Logic Level | 2
Arrival Clock Path Delay | cell: 0.952, 43.415%; route: 1.241, 56.585%
Arrival Data Path Delay | cell: 0.138, 51.000%; route: 0.005, 2.000%; tC2Q: 0.127, 47.000%
Required Clock Path Delay | cell: 0.952, 43.415%; route: 1.241, 56.585%

### Path17

Path Summary:

Slack | 0.247
Data Arrival Time | 2.456
Data Required Time | 2.209
From | g_sound.u_perc_env_bank/gen_perc[3].level_r_6_s0
To | g_sound.u_perc_env_bank/gen_perc[3].level_r_6_s0
Launch Clk | clk_sys:[R]
Latch Clk | clk_sys:[R]

Data Arrival Path:

AT | DELAY | TYPE | RF | FANOUT | LOC | NODE
0.000 | 0.000 | | | | | active clock edge time
0.000 | 0.000 | | | | | clk_sys
0.000 | 0.000 | tCL | RR | 1 | IOB117[B] | clk_ibuf/I
0.952 | 0.952 | tINS | RR | 15774 | IOB117[B] | clk_ibuf/O
2.186 | 1.234 | tNET | RR | 1 | R40C143[1][A] | g_sound.u_perc_env_bank/gen_perc[3].level_r_6_s0/CLK
2.313 | 0.127 | tC2Q | RF | 4 | R40C143[1][A] | g_sound.u_perc_env_bank/gen_perc[3].level_r_6_s0/Q
2.318 | 0.005 | tNET | FF | 1 | R40C143[1][A] | g_sound.u_perc_env_bank/n1220_s2/I2
2.456 | 0.138 | tINS | FF | 1 | R40C143[1][A] | g_sound.u_perc_env_bank/n1220_s2/F
2.456 | 0.000 | tNET | FF | 1 | R40C143[1][A] | g_sound.u_perc_env_bank/gen_perc[3].level_r_6_s0/D

Data Required Path:

AT | DELAY | TYPE | RF | FANOUT | LOC | NODE
0.000 | 0.000 | | | | | active clock edge time
0.000 | 0.000 | | | | | clk_sys
0.000 | 0.000 | tCL | RR | 1 | IOB117[B] | clk_ibuf/I
0.952 | 0.952 | tINS | RR | 15774 | IOB117[B] | clk_ibuf/O
2.186 | 1.234 | tNET | RR | 1 | R40C143[1][A] | g_sound.u_perc_env_bank/gen_perc[3].level_r_6_s0/CLK
2.209 | 0.022 | tHld | | 1 | R40C143[1][A] | g_sound.u_perc_env_bank/gen_perc[3].level_r_6_s0

Path Statistics:

Clock Skew | 0.000
Hold Relationship | 0.000
Logic Level | 2
Arrival Clock Path Delay | cell: 0.952, 43.558%; route: 1.234, 56.442%
Arrival Data Path Delay | cell: 0.138, 51.000%; route: 0.005, 2.000%; tC2Q: 0.127, 47.000%
Required Clock Path Delay | cell: 0.952, 43.558%; route: 1.234, 56.442%

### Path18

Path Summary:

Slack | 0.247
Data Arrival Time | 2.460
Data Required Time | 2.212
From | g_sound.u_perc_env_bank/gen_perc[1].level_r_7_s0
To | g_sound.u_perc_env_bank/gen_perc[1].level_r_7_s0
Launch Clk | clk_sys:[R]
Latch Clk | clk_sys:[R]

Data Arrival Path:

AT | DELAY | TYPE | RF | FANOUT | LOC | NODE
0.000 | 0.000 | | | | | active clock edge time
0.000 | 0.000 | | | | | clk_sys
0.000 | 0.000 | tCL | RR | 1 | IOB117[B] | clk_ibuf/I
0.952 | 0.952 | tINS | RR | 15774 | IOB117[B] | clk_ibuf/O
2.190 | 1.237 | tNET | RR | 1 | R37C142[1][A] | g_sound.u_perc_env_bank/gen_perc[1].level_r_7_s0/CLK
2.317 | 0.127 | tC2Q | RF | 6 | R37C142[1][A] | g_sound.u_perc_env_bank/gen_perc[1].level_r_7_s0/Q
2.322 | 0.005 | tNET | FF | 1 | R37C142[1][A] | g_sound.u_perc_env_bank/n523_s2/I3
2.460 | 0.138 | tINS | FF | 1 | R37C142[1][A] | g_sound.u_perc_env_bank/n523_s2/F
2.460 | 0.000 | tNET | FF | 1 | R37C142[1][A] | g_sound.u_perc_env_bank/gen_perc[1].level_r_7_s0/D

Data Required Path:

AT | DELAY | TYPE | RF | FANOUT | LOC | NODE
0.000 | 0.000 | | | | | active clock edge time
0.000 | 0.000 | | | | | clk_sys
0.000 | 0.000 | tCL | RR | 1 | IOB117[B] | clk_ibuf/I
0.952 | 0.952 | tINS | RR | 15774 | IOB117[B] | clk_ibuf/O
2.190 | 1.237 | tNET | RR | 1 | R37C142[1][A] | g_sound.u_perc_env_bank/gen_perc[1].level_r_7_s0/CLK
2.212 | 0.022 | tHld | | 1 | R37C142[1][A] | g_sound.u_perc_env_bank/gen_perc[1].level_r_7_s0

Path Statistics:

Clock Skew | 0.000
Hold Relationship | 0.000
Logic Level | 2
Arrival Clock Path Delay | cell: 0.952, 43.487%; route: 1.237, 56.513%
Arrival Data Path Delay | cell: 0.138, 51.000%; route: 0.005, 2.000%; tC2Q: 0.127, 47.000%
Required Clock Path Delay | cell: 0.952, 43.487%; route: 1.237, 56.513%

### Path19

Path Summary:

Slack | 0.247
Data Arrival Time | 2.460
Data Required Time | 2.212
From | g_sound.u_perc_env_bank/gen_perc[0].level_r_7_s0
To | g_sound.u_perc_env_bank/gen_perc[0].level_r_7_s0
Launch Clk | clk_sys:[R]
Latch Clk | clk_sys:[R]

Data Arrival Path:

AT | DELAY | TYPE | RF | FANOUT | LOC | NODE
0.000 | 0.000 | | | | | active clock edge time
0.000 | 0.000 | | | | | clk_sys
0.000 | 0.000 | tCL | RR | 1 | IOB117[B] | clk_ibuf/I
0.952 | 0.952 | tINS | RR | 15774 | IOB117[B] | clk_ibuf/O
2.190 | 1.237 | tNET | RR | 1 | R34C142[0][A] | g_sound.u_perc_env_bank/gen_perc[0].level_r_7_s0/CLK
2.317 | 0.127 | tC2Q | RF | 6 | R34C142[0][A] | g_sound.u_perc_env_bank/gen_perc[0].level_r_7_s0/Q
2.322 | 0.005 | tNET | FF | 1 | R34C142[0][A] | g_sound.u_perc_env_bank/n175_s2/I3
2.460 | 0.138 | tINS | FF | 1 | R34C142[0][A] | g_sound.u_perc_env_bank/n175_s2/F
2.460 | 0.000 | tNET | FF | 1 | R34C142[0][A] | g_sound.u_perc_env_bank/gen_perc[0].level_r_7_s0/D

Data Required Path:

AT | DELAY | TYPE | RF | FANOUT | LOC | NODE
0.000 | 0.000 | | | | | active clock edge time
0.000 | 0.000 | | | | | clk_sys
0.000 | 0.000 | tCL | RR | 1 | IOB117[B] | clk_ibuf/I
0.952 | 0.952 | tINS | RR | 15774 | IOB117[B] | clk_ibuf/O
2.190 | 1.237 | tNET | RR | 1 | R34C142[0][A] | g_sound.u_perc_env_bank/gen_perc[0].level_r_7_s0/CLK
2.212 | 0.022 | tHld | | 1 | R34C142[0][A] | g_sound.u_perc_env_bank/gen_perc[0].level_r_7_s0

Path Statistics:

Clock Skew | 0.000
Hold Relationship | 0.000
Logic Level | 2
Arrival Clock Path Delay | cell: 0.952, 43.487%; route: 1.237, 56.513%
Arrival Data Path Delay | cell: 0.138, 51.000%; route: 0.005, 2.000%; tC2Q: 0.127, 47.000%
Required Clock Path Delay | cell: 0.952, 43.487%; route: 1.237, 56.513%

### Path20

Path Summary:

Slack | 0.247
Data Arrival Time | 2.460
Data Required Time | 2.212
From | g_sound.u_oscillator_bank/gen_lane[58].phase_q_31_s0
To | g_sound.u_oscillator_bank/gen_lane[58].phase_q_31_s0
Launch Clk | clk_sys:[R]
Latch Clk | clk_sys:[R]

Data Arrival Path:

AT | DELAY | TYPE | RF | FANOUT | LOC | NODE
0.000 | 0.000 | | | | | active clock edge time
0.000 | 0.000 | | | | | clk_sys
0.000 | 0.000 | tCL | RR | 1 | IOB117[B] | clk_ibuf/I
0.952 | 0.952 | tINS | RR | 15774 | IOB117[B] | clk_ibuf/O
2.190 | 1.237 | tNET | RR | 1 | R63C124[0][A] | g_sound.u_oscillator_bank/gen_lane[58].phase_q_31_s0/CLK
2.317 | 0.127 | tC2Q | RF | 2 | R63C124[0][A] | g_sound.u_oscillator_bank/gen_lane[58].phase_q_31_s0/Q
2.322 | 0.005 | tNET | FF | 1 | R63C124[0][A] | g_sound.u_oscillator_bank/n43491_s3/I2
2.460 | 0.138 | tINS | FF | 1 | R63C124[0][A] | g_sound.u_oscillator_bank/n43491_s3/F
2.460 | 0.000 | tNET | FF | 1 | R63C124[0][A] | g_sound.u_oscillator_bank/gen_lane[58].phase_q_31_s0/D

Data Required Path:

AT | DELAY | TYPE | RF | FANOUT | LOC | NODE
0.000 | 0.000 | | | | | active clock edge time
0.000 | 0.000 | | | | | clk_sys
0.000 | 0.000 | tCL | RR | 1 | IOB117[B] | clk_ibuf/I
0.952 | 0.952 | tINS | RR | 15774 | IOB117[B] | clk_ibuf/O
2.190 | 1.237 | tNET | RR | 1 | R63C124[0][A] | g_sound.u_oscillator_bank/gen_lane[58].phase_q_31_s0/CLK
2.212 | 0.022 | tHld | | 1 | R63C124[0][A] | g_sound.u_oscillator_bank/gen_lane[58].phase_q_31_s0

Path Statistics:

Clock Skew | 0.000
Hold Relationship | 0.000
Logic Level | 2
Arrival Clock Path Delay | cell: 0.952, 43.487%; route: 1.237, 56.513%
Arrival Data Path Delay | cell: 0.138, 51.000%; route: 0.005, 2.000%; tC2Q: 0.127, 47.000%
Required Clock Path Delay | cell: 0.952, 43.487%; route: 1.237, 56.513%

### Path21

Path Summary:

Slack | 0.247
Data Arrival Time | 2.460
Data Required Time | 2.212
From | g_sound.u_oscillator_bank/gen_lane[56].phase_q_31_s0
To | g_sound.u_oscillator_bank/gen_lane[56].phase_q_31_s0
Launch Clk | clk_sys:[R]
Latch Clk | clk_sys:[R]

Data Arrival Path:

AT | DELAY | TYPE | RF | FANOUT | LOC | NODE
0.000 | 0.000 | | | | | active clock edge time
0.000 | 0.000 | | | | | clk_sys
0.000 | 0.000 | tCL | RR | 1 | IOB117[B] | clk_ibuf/I
0.952 | 0.952 | tINS | RR | 15774 | IOB117[B] | clk_ibuf/O
2.190 | 1.237 | tNET | RR | 1 | R58C110[0][A] | g_sound.u_oscillator_bank/gen_lane[56].phase_q_31_s0/CLK
2.317 | 0.127 | tC2Q | RF | 2 | R58C110[0][A] | g_sound.u_oscillator_bank/gen_lane[56].phase_q_31_s0/Q
2.322 | 0.005 | tNET | FF | 1 | R58C110[0][A] | g_sound.u_oscillator_bank/n42009_s3/I2
2.460 | 0.138 | tINS | FF | 1 | R58C110[0][A] | g_sound.u_oscillator_bank/n42009_s3/F
2.460 | 0.000 | tNET | FF | 1 | R58C110[0][A] | g_sound.u_oscillator_bank/gen_lane[56].phase_q_31_s0/D

Data Required Path:

AT | DELAY | TYPE | RF | FANOUT | LOC | NODE
0.000 | 0.000 | | | | | active clock edge time
0.000 | 0.000 | | | | | clk_sys
0.000 | 0.000 | tCL | RR | 1 | IOB117[B] | clk_ibuf/I
0.952 | 0.952 | tINS | RR | 15774 | IOB117[B] | clk_ibuf/O
2.190 | 1.237 | tNET | RR | 1 | R58C110[0][A] | g_sound.u_oscillator_bank/gen_lane[56].phase_q_31_s0/CLK
2.212 | 0.022 | tHld | | 1 | R58C110[0][A] | g_sound.u_oscillator_bank/gen_lane[56].phase_q_31_s0

Path Statistics:

Clock Skew | 0.000
Hold Relationship | 0.000
Logic Level | 2
Arrival Clock Path Delay | cell: 0.952, 43.487%; route: 1.237, 56.513%
Arrival Data Path Delay | cell: 0.138, 51.000%; route: 0.005, 2.000%; tC2Q: 0.127, 47.000%
Required Clock Path Delay | cell: 0.952, 43.487%; route: 1.237, 56.513%

### Path22

Path Summary:

Slack | 0.247
Data Arrival Time | 2.456
Data Required Time | 2.209
From | g_sound.u_oscillator_bank/gen_lane[55].phase_q_31_s0
To | g_sound.u_oscillator_bank/gen_lane[55].phase_q_31_s0
Launch Clk | clk_sys:[R]
Latch Clk | clk_sys:[R]

Data Arrival Path:

AT | DELAY | TYPE | RF | FANOUT | LOC | NODE
0.000 | 0.000 | | | | | active clock edge time
0.000 | 0.000 | | | | | clk_sys
0.000 | 0.000 | tCL | RR | 1 | IOB117[B] | clk_ibuf/I
0.952 | 0.952 | tINS | RR | 15774 | IOB117[B] | clk_ibuf/O
2.186 | 1.234 | tNET | RR | 1 | R71C119[0][A] | g_sound.u_oscillator_bank/gen_lane[55].phase_q_31_s0/CLK
2.313 | 0.127 | tC2Q | RF | 2 | R71C119[0][A] | g_sound.u_oscillator_bank/gen_lane[55].phase_q_31_s0/Q
2.318 | 0.005 | tNET | FF | 1 | R71C119[0][A] | g_sound.u_oscillator_bank/n41268_s3/I2
2.456 | 0.138 | tINS | FF | 1 | R71C119[0][A] | g_sound.u_oscillator_bank/n41268_s3/F
2.456 | 0.000 | tNET | FF | 1 | R71C119[0][A] | g_sound.u_oscillator_bank/gen_lane[55].phase_q_31_s0/D

Data Required Path:

AT | DELAY | TYPE | RF | FANOUT | LOC | NODE
0.000 | 0.000 | | | | | active clock edge time
0.000 | 0.000 | | | | | clk_sys
0.000 | 0.000 | tCL | RR | 1 | IOB117[B] | clk_ibuf/I
0.952 | 0.952 | tINS | RR | 15774 | IOB117[B] | clk_ibuf/O
2.186 | 1.234 | tNET | RR | 1 | R71C119[0][A] | g_sound.u_oscillator_bank/gen_lane[55].phase_q_31_s0/CLK
2.209 | 0.022 | tHld | | 1 | R71C119[0][A] | g_sound.u_oscillator_bank/gen_lane[55].phase_q_31_s0

Path Statistics:

Clock Skew | 0.000
Hold Relationship | 0.000
Logic Level | 2
Arrival Clock Path Delay | cell: 0.952, 43.558%; route: 1.234, 56.442%
Arrival Data Path Delay | cell: 0.138, 51.000%; route: 0.005, 2.000%; tC2Q: 0.127, 47.000%
Required Clock Path Delay | cell: 0.952, 43.558%; route: 1.234, 56.442%

### Path23

Path Summary:

Slack | 0.247
Data Arrival Time | 2.456
Data Required Time | 2.209
From | g_sound.u_oscillator_bank/gen_lane[54].phase_q_31_s0
To | g_sound.u_oscillator_bank/gen_lane[54].phase_q_31_s0
Launch Clk | clk_sys:[R]
Latch Clk | clk_sys:[R]

Data Arrival Path:

AT | DELAY | TYPE | RF | FANOUT | LOC | NODE
0.000 | 0.000 | | | | | active clock edge time
0.000 | 0.000 | | | | | clk_sys
0.000 | 0.000 | tCL | RR | 1 | IOB117[B] | clk_ibuf/I
0.952 | 0.952 | tINS | RR | 15774 | IOB117[B] | clk_ibuf/O
2.186 | 1.234 | tNET | RR | 1 | R61C119[0][A] | g_sound.u_oscillator_bank/gen_lane[54].phase_q_31_s0/CLK
2.313 | 0.127 | tC2Q | RF | 2 | R61C119[0][A] | g_sound.u_oscillator_bank/gen_lane[54].phase_q_31_s0/Q
2.318 | 0.005 | tNET | FF | 1 | R61C119[0][A] | g_sound.u_oscillator_bank/n40527_s3/I2
2.456 | 0.138 | tINS | FF | 1 | R61C119[0][A] | g_sound.u_oscillator_bank/n40527_s3/F
2.456 | 0.000 | tNET | FF | 1 | R61C119[0][A] | g_sound.u_oscillator_bank/gen_lane[54].phase_q_31_s0/D

Data Required Path:

AT | DELAY | TYPE | RF | FANOUT | LOC | NODE
0.000 | 0.000 | | | | | active clock edge time
0.000 | 0.000 | | | | | clk_sys
0.000 | 0.000 | tCL | RR | 1 | IOB117[B] | clk_ibuf/I
0.952 | 0.952 | tINS | RR | 15774 | IOB117[B] | clk_ibuf/O
2.186 | 1.234 | tNET | RR | 1 | R61C119[0][A] | g_sound.u_oscillator_bank/gen_lane[54].phase_q_31_s0/CLK
2.209 | 0.022 | tHld | | 1 | R61C119[0][A] | g_sound.u_oscillator_bank/gen_lane[54].phase_q_31_s0

Path Statistics:

Clock Skew | 0.000
Hold Relationship | 0.000
Logic Level | 2
Arrival Clock Path Delay | cell: 0.952, 43.558%; route: 1.234, 56.442%
Arrival Data Path Delay | cell: 0.138, 51.000%; route: 0.005, 2.000%; tC2Q: 0.127, 47.000%
Required Clock Path Delay | cell: 0.952, 43.558%; route: 1.234, 56.442%

### Path24

Path Summary:

Slack | 0.247
Data Arrival Time | 2.460
Data Required Time | 2.212
From | g_sound.u_oscillator_bank/gen_lane[53].phase_q_31_s0
To | g_sound.u_oscillator_bank/gen_lane[53].phase_q_31_s0
Launch Clk | clk_sys:[R]
Latch Clk | clk_sys:[R]

Data Arrival Path:

AT | DELAY | TYPE | RF | FANOUT | LOC | NODE
0.000 | 0.000 | | | | | active clock edge time
0.000 | 0.000 | | | | | clk_sys
0.000 | 0.000 | tCL | RR | 1 | IOB117[B] | clk_ibuf/I
0.952 | 0.952 | tINS | RR | 15774 | IOB117[B] | clk_ibuf/O
2.190 | 1.237 | tNET | RR | 1 | R66C110[1][A] | g_sound.u_oscillator_bank/gen_lane[53].phase_q_31_s0/CLK
2.317 | 0.127 | tC2Q | RF | 2 | R66C110[1][A] | g_sound.u_oscillator_bank/gen_lane[53].phase_q_31_s0/Q
2.322 | 0.005 | tNET | FF | 1 | R66C110[1][A] | g_sound.u_oscillator_bank/n39786_s3/I2
2.460 | 0.138 | tINS | FF | 1 | R66C110[1][A] | g_sound.u_oscillator_bank/n39786_s3/F
2.460 | 0.000 | tNET | FF | 1 | R66C110[1][A] | g_sound.u_oscillator_bank/gen_lane[53].phase_q_31_s0/D

Data Required Path:

AT | DELAY | TYPE | RF | FANOUT | LOC | NODE
0.000 | 0.000 | | | | | active clock edge time
0.000 | 0.000 | | | | | clk_sys
0.000 | 0.000 | tCL | RR | 1 | IOB117[B] | clk_ibuf/I
0.952 | 0.952 | tINS | RR | 15774 | IOB117[B] | clk_ibuf/O
2.190 | 1.237 | tNET | RR | 1 | R66C110[1][A] | g_sound.u_oscillator_bank/gen_lane[53].phase_q_31_s0/CLK
2.212 | 0.022 | tHld | | 1 | R66C110[1][A] | g_sound.u_oscillator_bank/gen_lane[53].phase_q_31_s0

Path Statistics:

Clock Skew | 0.000
Hold Relationship | 0.000
Logic Level | 2
Arrival Clock Path Delay | cell: 0.952, 43.487%; route: 1.237, 56.513%
Arrival Data Path Delay | cell: 0.138, 51.000%; route: 0.005, 2.000%; tC2Q: 0.127, 47.000%
Required Clock Path Delay | cell: 0.952, 43.487%; route: 1.237, 56.513%

### Path25

Path Summary:

Slack | 0.247
Data Arrival Time | 2.460
Data Required Time | 2.212
From | g_sound.u_oscillator_bank/gen_lane[52].phase_q_31_s0
To | g_sound.u_oscillator_bank/gen_lane[52].phase_q_31_s0
Launch Clk | clk_sys:[R]
Latch Clk | clk_sys:[R]

Data Arrival Path:

AT | DELAY | TYPE | RF | FANOUT | LOC | NODE
0.000 | 0.000 | | | | | active clock edge time
0.000 | 0.000 | | | | | clk_sys
0.000 | 0.000 | tCL | RR | 1 | IOB117[B] | clk_ibuf/I
0.952 | 0.952 | tINS | RR | 15774 | IOB117[B] | clk_ibuf/O
2.190 | 1.237 | tNET | RR | 1 | R62C110[1][A] | g_sound.u_oscillator_bank/gen_lane[52].phase_q_31_s0/CLK
2.317 | 0.127 | tC2Q | RF | 2 | R62C110[1][A] | g_sound.u_oscillator_bank/gen_lane[52].phase_q_31_s0/Q
2.322 | 0.005 | tNET | FF | 1 | R62C110[1][A] | g_sound.u_oscillator_bank/n39045_s3/I2
2.460 | 0.138 | tINS | FF | 1 | R62C110[1][A] | g_sound.u_oscillator_bank/n39045_s3/F
2.460 | 0.000 | tNET | FF | 1 | R62C110[1][A] | g_sound.u_oscillator_bank/gen_lane[52].phase_q_31_s0/D

Data Required Path:

AT | DELAY | TYPE | RF | FANOUT | LOC | NODE
0.000 | 0.000 | | | | | active clock edge time
0.000 | 0.000 | | | | | clk_sys
0.000 | 0.000 | tCL | RR | 1 | IOB117[B] | clk_ibuf/I
0.952 | 0.952 | tINS | RR | 15774 | IOB117[B] | clk_ibuf/O
2.190 | 1.237 | tNET | RR | 1 | R62C110[1][A] | g_sound.u_oscillator_bank/gen_lane[52].phase_q_31_s0/CLK
2.212 | 0.022 | tHld | | 1 | R62C110[1][A] | g_sound.u_oscillator_bank/gen_lane[52].phase_q_31_s0

Path Statistics:

Clock Skew | 0.000
Hold Relationship | 0.000
Logic Level | 2
Arrival Clock Path Delay | cell: 0.952, 43.487%; route: 1.237, 56.513%
Arrival Data Path Delay | cell: 0.138, 51.000%; route: 0.005, 2.000%; tC2Q: 0.127, 47.000%
Required Clock Path Delay | cell: 0.952, 43.487%; route: 1.237, 56.513%

### Recovery Analysis Report

#### Report Command:report_timing -recovery -max_paths 25 -max_common_paths 1

### Path1

Path Summary:

Slack | 1.481
Data Arrival Time | 26.480
Data Required Time | 27.961
From | u_rst_sync/sync_chain_1_s0
To | u_hdmi/u_serializer/lanes[3].u_oser
Launch Clk | clk_sys:[R]
Latch Clk | serial_clk:[R]

Data Arrival Path:

AT | DELAY | TYPE | RF | FANOUT | LOC | NODE
20.000 | 20.000 | | | | | active clock edge time
20.000 | 0.000 | | | | | clk_sys
20.000 | 0.000 | tCL | RR | 1 | IOB117[B] | clk_ibuf/I
21.288 | 1.288 | tINS | RR | 15774 | IOB117[B] | clk_ibuf/O
24.133 | 2.845 | tNET | RR | 1 | R73C54[1][A] | u_rst_sync/sync_chain_1_s0/CLK
24.464 | 0.331 | tC2Q | RF | 12951 | R73C54[1][A] | u_rst_sync/sync_chain_1_s0/Q
26.480 | 2.016 | tNET | FF | 1 | IOR24[A] | u_hdmi/u_serializer/lanes[3].u_oser/RESET

Data Required Path:

AT | DELAY | TYPE | RF | FANOUT | LOC | NODE
24.000 | 24.000 | | | | | active clock edge time
24.000 | 0.000 | | | | | serial_clk
28.133 | 4.133 | tCL | RR | 4 | PLL_R[1] | u_hdmi/u_clk/u_pll/CLKOUT0
28.133 | 0.000 | tNET | RR | 1 | IOR24[A] | u_hdmi/u_serializer/lanes[3].u_oser/FCLK
28.098 | -0.035 | tUnc
27.961 | -0.138 | tSu | | 1 | IOR24[A] | u_hdmi/u_serializer/lanes[3].u_oser

Path Statistics:

Clock Skew | 0.000
Setup Relationship | 4.000
Logic Level | 1
Arrival Clock Path Delay | cell: 1.288, 31.169%; route: 2.845, 68.831%
Arrival Data Path Delay | cell: 0.000, 0.000%; route: 2.016, 85.906%; tC2Q: 0.331, 14.094%
Required Clock Path Delay | cell: 0.000, 0.000%; route: 0.000, 0.000%

### Path2

Path Summary:

Slack | 1.481
Data Arrival Time | 26.480
Data Required Time | 27.961
From | u_rst_sync/sync_chain_1_s0
To | u_hdmi/u_serializer/lanes[2].u_oser
Launch Clk | clk_sys:[R]
Latch Clk | serial_clk:[R]

Data Arrival Path:

AT | DELAY | TYPE | RF | FANOUT | LOC | NODE
20.000 | 20.000 | | | | | active clock edge time
20.000 | 0.000 | | | | | clk_sys
20.000 | 0.000 | tCL | RR | 1 | IOB117[B] | clk_ibuf/I
21.288 | 1.288 | tINS | RR | 15774 | IOB117[B] | clk_ibuf/O
24.133 | 2.845 | tNET | RR | 1 | R73C54[1][A] | u_rst_sync/sync_chain_1_s0/CLK
24.464 | 0.331 | tC2Q | RF | 12951 | R73C54[1][A] | u_rst_sync/sync_chain_1_s0/Q
26.480 | 2.016 | tNET | FF | 1 | IOR39[A] | u_hdmi/u_serializer/lanes[2].u_oser/RESET

Data Required Path:

AT | DELAY | TYPE | RF | FANOUT | LOC | NODE
24.000 | 24.000 | | | | | active clock edge time
24.000 | 0.000 | | | | | serial_clk
28.133 | 4.133 | tCL | RR | 4 | PLL_R[1] | u_hdmi/u_clk/u_pll/CLKOUT0
28.133 | 0.000 | tNET | RR | 1 | IOR39[A] | u_hdmi/u_serializer/lanes[2].u_oser/FCLK
28.098 | -0.035 | tUnc
27.961 | -0.138 | tSu | | 1 | IOR39[A] | u_hdmi/u_serializer/lanes[2].u_oser

Path Statistics:

Clock Skew | 0.000
Setup Relationship | 4.000
Logic Level | 1
Arrival Clock Path Delay | cell: 1.288, 31.169%; route: 2.845, 68.831%
Arrival Data Path Delay | cell: 0.000, 0.000%; route: 2.016, 85.906%; tC2Q: 0.331, 14.094%
Required Clock Path Delay | cell: 0.000, 0.000%; route: 0.000, 0.000%

### Path3

Path Summary:

Slack | 1.481
Data Arrival Time | 26.480
Data Required Time | 27.961
From | u_rst_sync/sync_chain_1_s0
To | u_hdmi/u_serializer/lanes[1].u_oser
Launch Clk | clk_sys:[R]
Latch Clk | serial_clk:[R]

Data Arrival Path:

AT | DELAY | TYPE | RF | FANOUT | LOC | NODE
20.000 | 20.000 | | | | | active clock edge time
20.000 | 0.000 | | | | | clk_sys
20.000 | 0.000 | tCL | RR | 1 | IOB117[B] | clk_ibuf/I
21.288 | 1.288 | tINS | RR | 15774 | IOB117[B] | clk_ibuf/O
24.133 | 2.845 | tNET | RR | 1 | R73C54[1][A] | u_rst_sync/sync_chain_1_s0/CLK
24.464 | 0.331 | tC2Q | RF | 12951 | R73C54[1][A] | u_rst_sync/sync_chain_1_s0/Q
26.480 | 2.016 | tNET | FF | 1 | IOR22[A] | u_hdmi/u_serializer/lanes[1].u_oser/RESET

Data Required Path:

AT | DELAY | TYPE | RF | FANOUT | LOC | NODE
24.000 | 24.000 | | | | | active clock edge time
24.000 | 0.000 | | | | | serial_clk
28.133 | 4.133 | tCL | RR | 4 | PLL_R[1] | u_hdmi/u_clk/u_pll/CLKOUT0
28.133 | 0.000 | tNET | RR | 1 | IOR22[A] | u_hdmi/u_serializer/lanes[1].u_oser/FCLK
28.098 | -0.035 | tUnc
27.961 | -0.138 | tSu | | 1 | IOR22[A] | u_hdmi/u_serializer/lanes[1].u_oser

Path Statistics:

Clock Skew | 0.000
Setup Relationship | 4.000
Logic Level | 1
Arrival Clock Path Delay | cell: 1.288, 31.169%; route: 2.845, 68.831%
Arrival Data Path Delay | cell: 0.000, 0.000%; route: 2.016, 85.906%; tC2Q: 0.331, 14.094%
Required Clock Path Delay | cell: 0.000, 0.000%; route: 0.000, 0.000%

### Path4

Path Summary:

Slack | 1.481
Data Arrival Time | 26.480
Data Required Time | 27.961
From | u_rst_sync/sync_chain_1_s0
To | u_hdmi/u_serializer/lanes[0].u_oser
Launch Clk | clk_sys:[R]
Latch Clk | serial_clk:[R]

Data Arrival Path:

AT | DELAY | TYPE | RF | FANOUT | LOC | NODE
20.000 | 20.000 | | | | | active clock edge time
20.000 | 0.000 | | | | | clk_sys
20.000 | 0.000 | tCL | RR | 1 | IOB117[B] | clk_ibuf/I
21.288 | 1.288 | tINS | RR | 15774 | IOB117[B] | clk_ibuf/O
24.133 | 2.845 | tNET | RR | 1 | R73C54[1][A] | u_rst_sync/sync_chain_1_s0/CLK
24.464 | 0.331 | tC2Q | RF | 12951 | R73C54[1][A] | u_rst_sync/sync_chain_1_s0/Q
26.480 | 2.016 | tNET | FF | 1 | IOR26[A] | u_hdmi/u_serializer/lanes[0].u_oser/RESET

Data Required Path:

AT | DELAY | TYPE | RF | FANOUT | LOC | NODE
24.000 | 24.000 | | | | | active clock edge time
24.000 | 0.000 | | | | | serial_clk
28.133 | 4.133 | tCL | RR | 4 | PLL_R[1] | u_hdmi/u_clk/u_pll/CLKOUT0
28.133 | 0.000 | tNET | RR | 1 | IOR26[A] | u_hdmi/u_serializer/lanes[0].u_oser/FCLK
28.098 | -0.035 | tUnc
27.961 | -0.138 | tSu | | 1 | IOR26[A] | u_hdmi/u_serializer/lanes[0].u_oser

Path Statistics:

Clock Skew | 0.000
Setup Relationship | 4.000
Logic Level | 1
Arrival Clock Path Delay | cell: 1.288, 31.169%; route: 2.845, 68.831%
Arrival Data Path Delay | cell: 0.000, 0.000%; route: 2.016, 85.906%; tC2Q: 0.331, 14.094%
Required Clock Path Delay | cell: 0.000, 0.000%; route: 0.000, 0.000%

### Path5

Path Summary:

Slack | 1.482
Data Arrival Time | 6.480
Data Required Time | 7.963
From | u_rst_sync/sync_chain_1_s0
To | u_hdmi/u_serializer/lanes[0].u_oser
Launch Clk | clk_sys:[R]
Latch Clk | serial_clk:[F]

Data Arrival Path:

AT | DELAY | TYPE | RF | FANOUT | LOC | NODE
0.000 | 0.000 | | | | | active clock edge time
0.000 | 0.000 | | | | | clk_sys
0.000 | 0.000 | tCL | RR | 1 | IOB117[B] | clk_ibuf/I
1.288 | 1.288 | tINS | RR | 15774 | IOB117[B] | clk_ibuf/O
4.133 | 2.845 | tNET | RR | 1 | R73C54[1][A] | u_rst_sync/sync_chain_1_s0/CLK
4.464 | 0.331 | tC2Q | RF | 12951 | R73C54[1][A] | u_rst_sync/sync_chain_1_s0/Q
6.480 | 2.016 | tNET | FF | 1 | IOR26[A] | u_hdmi/u_serializer/lanes[0].u_oser/RESET

Data Required Path:

AT | DELAY | TYPE | RF | FANOUT | LOC | NODE
4.000 | 4.000 | | | | | active clock edge time
4.000 | 0.000 | | | | | serial_clk
8.133 | 4.133 | tCL | FF | 4 | PLL_R[1] | u_hdmi/u_clk/u_pll/CLKOUT0
8.133 | 0.000 | tNET | FF | 1 | IOR26[A] | u_hdmi/u_serializer/lanes[0].u_oser/FCLK
8.098 | -0.035 | tUnc
7.963 | -0.136 | tSu | | 1 | IOR26[A] | u_hdmi/u_serializer/lanes[0].u_oser

Path Statistics:

Clock Skew | 0.000
Setup Relationship | 4.000
Logic Level | 1
Arrival Clock Path Delay | cell: 1.288, 31.169%; route: 2.845, 68.831%
Arrival Data Path Delay | cell: 0.000, 0.000%; route: 2.016, 85.906%; tC2Q: 0.331, 14.094%
Required Clock Path Delay | cell: 0.000, 0.000%; route: 0.000, 0.000%

### Path6

Path Summary:

Slack | 1.482
Data Arrival Time | 6.480
Data Required Time | 7.963
From | u_rst_sync/sync_chain_1_s0
To | u_hdmi/u_serializer/lanes[1].u_oser
Launch Clk | clk_sys:[R]
Latch Clk | serial_clk:[F]

Data Arrival Path:

AT | DELAY | TYPE | RF | FANOUT | LOC | NODE
0.000 | 0.000 | | | | | active clock edge time
0.000 | 0.000 | | | | | clk_sys
0.000 | 0.000 | tCL | RR | 1 | IOB117[B] | clk_ibuf/I
1.288 | 1.288 | tINS | RR | 15774 | IOB117[B] | clk_ibuf/O
4.133 | 2.845 | tNET | RR | 1 | R73C54[1][A] | u_rst_sync/sync_chain_1_s0/CLK
4.464 | 0.331 | tC2Q | RF | 12951 | R73C54[1][A] | u_rst_sync/sync_chain_1_s0/Q
6.480 | 2.016 | tNET | FF | 1 | IOR22[A] | u_hdmi/u_serializer/lanes[1].u_oser/RESET

Data Required Path:

AT | DELAY | TYPE | RF | FANOUT | LOC | NODE
4.000 | 4.000 | | | | | active clock edge time
4.000 | 0.000 | | | | | serial_clk
8.133 | 4.133 | tCL | FF | 4 | PLL_R[1] | u_hdmi/u_clk/u_pll/CLKOUT0
8.133 | 0.000 | tNET | FF | 1 | IOR22[A] | u_hdmi/u_serializer/lanes[1].u_oser/FCLK
8.098 | -0.035 | tUnc
7.963 | -0.136 | tSu | | 1 | IOR22[A] | u_hdmi/u_serializer/lanes[1].u_oser

Path Statistics:

Clock Skew | 0.000
Setup Relationship | 4.000
Logic Level | 1
Arrival Clock Path Delay | cell: 1.288, 31.169%; route: 2.845, 68.831%
Arrival Data Path Delay | cell: 0.000, 0.000%; route: 2.016, 85.906%; tC2Q: 0.331, 14.094%
Required Clock Path Delay | cell: 0.000, 0.000%; route: 0.000, 0.000%

### Path7

Path Summary:

Slack | 1.482
Data Arrival Time | 6.480
Data Required Time | 7.963
From | u_rst_sync/sync_chain_1_s0
To | u_hdmi/u_serializer/lanes[2].u_oser
Launch Clk | clk_sys:[R]
Latch Clk | serial_clk:[F]

Data Arrival Path:

AT | DELAY | TYPE | RF | FANOUT | LOC | NODE
0.000 | 0.000 | | | | | active clock edge time
0.000 | 0.000 | | | | | clk_sys
0.000 | 0.000 | tCL | RR | 1 | IOB117[B] | clk_ibuf/I
1.288 | 1.288 | tINS | RR | 15774 | IOB117[B] | clk_ibuf/O
4.133 | 2.845 | tNET | RR | 1 | R73C54[1][A] | u_rst_sync/sync_chain_1_s0/CLK
4.464 | 0.331 | tC2Q | RF | 12951 | R73C54[1][A] | u_rst_sync/sync_chain_1_s0/Q
6.480 | 2.016 | tNET | FF | 1 | IOR39[A] | u_hdmi/u_serializer/lanes[2].u_oser/RESET

Data Required Path:

AT | DELAY | TYPE | RF | FANOUT | LOC | NODE
4.000 | 4.000 | | | | | active clock edge time
4.000 | 0.000 | | | | | serial_clk
8.133 | 4.133 | tCL | FF | 4 | PLL_R[1] | u_hdmi/u_clk/u_pll/CLKOUT0
8.133 | 0.000 | tNET | FF | 1 | IOR39[A] | u_hdmi/u_serializer/lanes[2].u_oser/FCLK
8.098 | -0.035 | tUnc
7.963 | -0.136 | tSu | | 1 | IOR39[A] | u_hdmi/u_serializer/lanes[2].u_oser

Path Statistics:

Clock Skew | 0.000
Setup Relationship | 4.000
Logic Level | 1
Arrival Clock Path Delay | cell: 1.288, 31.169%; route: 2.845, 68.831%
Arrival Data Path Delay | cell: 0.000, 0.000%; route: 2.016, 85.906%; tC2Q: 0.331, 14.094%
Required Clock Path Delay | cell: 0.000, 0.000%; route: 0.000, 0.000%

### Path8

Path Summary:

Slack | 1.482
Data Arrival Time | 6.480
Data Required Time | 7.963
From | u_rst_sync/sync_chain_1_s0
To | u_hdmi/u_serializer/lanes[3].u_oser
Launch Clk | clk_sys:[R]
Latch Clk | serial_clk:[F]

Data Arrival Path:

AT | DELAY | TYPE | RF | FANOUT | LOC | NODE
0.000 | 0.000 | | | | | active clock edge time
0.000 | 0.000 | | | | | clk_sys
0.000 | 0.000 | tCL | RR | 1 | IOB117[B] | clk_ibuf/I
1.288 | 1.288 | tINS | RR | 15774 | IOB117[B] | clk_ibuf/O
4.133 | 2.845 | tNET | RR | 1 | R73C54[1][A] | u_rst_sync/sync_chain_1_s0/CLK
4.464 | 0.331 | tC2Q | RF | 12951 | R73C54[1][A] | u_rst_sync/sync_chain_1_s0/Q
6.480 | 2.016 | tNET | FF | 1 | IOR24[A] | u_hdmi/u_serializer/lanes[3].u_oser/RESET

Data Required Path:

AT | DELAY | TYPE | RF | FANOUT | LOC | NODE
4.000 | 4.000 | | | | | active clock edge time
4.000 | 0.000 | | | | | serial_clk
8.133 | 4.133 | tCL | FF | 4 | PLL_R[1] | u_hdmi/u_clk/u_pll/CLKOUT0
8.133 | 0.000 | tNET | FF | 1 | IOR24[A] | u_hdmi/u_serializer/lanes[3].u_oser/FCLK
8.098 | -0.035 | tUnc
7.963 | -0.136 | tSu | | 1 | IOR24[A] | u_hdmi/u_serializer/lanes[3].u_oser

Path Statistics:

Clock Skew | 0.000
Setup Relationship | 4.000
Logic Level | 1
Arrival Clock Path Delay | cell: 1.288, 31.169%; route: 2.845, 68.831%
Arrival Data Path Delay | cell: 0.000, 0.000%; route: 2.016, 85.906%; tC2Q: 0.331, 14.094%
Required Clock Path Delay | cell: 0.000, 0.000%; route: 0.000, 0.000%

### Path9

Path Summary:

Slack | 11.807
Data Arrival Time | 11.830
Data Required Time | 23.637
From | u_rst_sync/sync_chain_1_s0
To | g_sound.u_calib0/n840_s
Launch Clk | clk_sys:[R]
Latch Clk | clk_sys:[R]

Data Arrival Path:

AT | DELAY | TYPE | RF | FANOUT | LOC | NODE
0.000 | 0.000 | | | | | active clock edge time
0.000 | 0.000 | | | | | clk_sys
0.000 | 0.000 | tCL | RR | 1 | IOB117[B] | clk_ibuf/I
1.288 | 1.288 | tINS | RR | 15774 | IOB117[B] | clk_ibuf/O
4.133 | 2.845 | tNET | RR | 1 | R73C54[1][A] | u_rst_sync/sync_chain_1_s0/CLK
4.478 | 0.344 | tC2Q | RR | 12951 | R73C54[1][A] | u_rst_sync/sync_chain_1_s0/Q
6.678 | 2.201 | tNET | RR | 1 | R34C139[3][B] | u_timbre_btn_debounce/n191_s2/I0
7.022 | 0.344 | tINS | RF | 10 | R34C139[3][B] | u_timbre_btn_debounce/n191_s2/F
11.830 | 4.807 | tNET | FF | 1 | DSP_R28[1] | g_sound.u_calib0/n840_s/RESET[0]

Data Required Path:

AT | DELAY | TYPE | RF | FANOUT | LOC | NODE
20.000 | 20.000 | | | | | active clock edge time
20.000 | 0.000 | | | | | clk_sys
20.000 | 0.000 | tCL | RR | 1 | IOB117[B] | clk_ibuf/I
21.288 | 1.288 | tINS | RR | 15774 | IOB117[B] | clk_ibuf/O
24.142 | 2.854 | tNET | RR | 1 | DSP_R28[1] | g_sound.u_calib0/n840_s/CLK[0]
23.637 | -0.505 | tSu | | 1 | DSP_R28[1] | g_sound.u_calib0/n840_s

Path Statistics:

Clock Skew | 0.008
Setup Relationship | 20.000
Logic Level | 2
Arrival Clock Path Delay | cell: 1.288, 31.169%; route: 2.845, 68.831%
Arrival Data Path Delay | cell: 0.344, 4.473%; route: 7.008, 91.054%; tC2Q: 0.344, 4.473%
Required Clock Path Delay | cell: 1.288, 31.105%; route: 2.854, 68.895%

### Path10

Path Summary:

Slack | 12.725
Data Arrival Time | 10.904
Data Required Time | 23.629
From | u_rst_sync/sync_chain_1_s0
To | g_sound.u_calib1/n840_s
Launch Clk | clk_sys:[R]
Latch Clk | clk_sys:[R]

Data Arrival Path:

AT | DELAY | TYPE | RF | FANOUT | LOC | NODE
0.000 | 0.000 | | | | | active clock edge time
0.000 | 0.000 | | | | | clk_sys
0.000 | 0.000 | tCL | RR | 1 | IOB117[B] | clk_ibuf/I
1.288 | 1.288 | tINS | RR | 15774 | IOB117[B] | clk_ibuf/O
4.133 | 2.845 | tNET | RR | 1 | R73C54[1][A] | u_rst_sync/sync_chain_1_s0/CLK
4.478 | 0.344 | tC2Q | RR | 12951 | R73C54[1][A] | u_rst_sync/sync_chain_1_s0/Q
6.678 | 2.201 | tNET | RR | 1 | R34C139[3][B] | u_timbre_btn_debounce/n191_s2/I0
7.022 | 0.344 | tINS | RF | 10 | R34C139[3][B] | u_timbre_btn_debounce/n191_s2/F
10.904 | 3.881 | tNET | FF | 1 | DSP_R28[6] | g_sound.u_calib1/n840_s/RESET[0]

Data Required Path:

AT | DELAY | TYPE | RF | FANOUT | LOC | NODE
20.000 | 20.000 | | | | | active clock edge time
20.000 | 0.000 | | | | | clk_sys
20.000 | 0.000 | tCL | RR | 1 | IOB117[B] | clk_ibuf/I
21.288 | 1.288 | tINS | RR | 15774 | IOB117[B] | clk_ibuf/O
24.133 | 2.845 | tNET | RR | 1 | DSP_R28[6] | g_sound.u_calib1/n840_s/CLK[0]
23.629 | -0.505 | tSu | | 1 | DSP_R28[6] | g_sound.u_calib1/n840_s

Path Statistics:

Clock Skew | 0.000
Setup Relationship | 20.000
Logic Level | 2
Arrival Clock Path Delay | cell: 1.288, 31.169%; route: 2.845, 68.831%
Arrival Data Path Delay | cell: 0.344, 5.085%; route: 6.082, 89.831%; tC2Q: 0.344, 5.085%
Required Clock Path Delay | cell: 1.288, 31.169%; route: 2.845, 68.831%

### Path11

Path Summary:

Slack | 17.334
Data Arrival Time | 6.487
Data Required Time | 23.821
From | u_rst_sync/sync_chain_1_s0
To | g_sound.u_looper/on_addr_r[13]_9_s0
Launch Clk | clk_sys:[R]
Latch Clk | clk_sys:[R]

Data Arrival Path:

AT | DELAY | TYPE | RF | FANOUT | LOC | NODE
0.000 | 0.000 | | | | | active clock edge time
0.000 | 0.000 | | | | | clk_sys
0.000 | 0.000 | tCL | RR | 1 | IOB117[B] | clk_ibuf/I
1.288 | 1.288 | tINS | RR | 15774 | IOB117[B] | clk_ibuf/O
4.133 | 2.845 | tNET | RR | 1 | R73C54[1][A] | u_rst_sync/sync_chain_1_s0/CLK
4.464 | 0.331 | tC2Q | RF | 12951 | R73C54[1][A] | u_rst_sync/sync_chain_1_s0/Q
6.487 | 2.023 | tNET | FF | 1 | R46C18[0][A] | g_sound.u_looper/on_addr_r[13]_9_s0/CLEAR

Data Required Path:

AT | DELAY | TYPE | RF | FANOUT | LOC | NODE
20.000 | 20.000 | | | | | active clock edge time
20.000 | 0.000 | | | | | clk_sys
20.000 | 0.000 | tCL | RR | 1 | IOB117[B] | clk_ibuf/I
21.288 | 1.288 | tINS | RR | 15774 | IOB117[B] | clk_ibuf/O
24.133 | 2.845 | tNET | RR | 1 | R46C18[0][A] | g_sound.u_looper/on_addr_r[13]_9_s0/CLK
23.821 | -0.313 | tSu | | 1 | R46C18[0][A] | g_sound.u_looper/on_addr_r[13]_9_s0

Path Statistics:

Clock Skew | 0.000
Setup Relationship | 20.000
Logic Level | 1
Arrival Clock Path Delay | cell: 1.288, 31.169%; route: 2.845, 68.831%
Arrival Data Path Delay | cell: 0.000, 0.000%; route: 2.023, 85.946%; tC2Q: 0.331, 14.054%
Required Clock Path Delay | cell: 1.288, 31.169%; route: 2.845, 68.831%

### Path12

Path Summary:

Slack | 17.334
Data Arrival Time | 6.487
Data Required Time | 23.821
From | u_rst_sync/sync_chain_1_s0
To | g_sound.u_looper/on_addr_r[9]_0_s0
Launch Clk | clk_sys:[R]
Latch Clk | clk_sys:[R]

Data Arrival Path:

AT | DELAY | TYPE | RF | FANOUT | LOC | NODE
0.000 | 0.000 | | | | | active clock edge time
0.000 | 0.000 | | | | | clk_sys
0.000 | 0.000 | tCL | RR | 1 | IOB117[B] | clk_ibuf/I
1.288 | 1.288 | tINS | RR | 15774 | IOB117[B] | clk_ibuf/O
4.133 | 2.845 | tNET | RR | 1 | R73C54[1][A] | u_rst_sync/sync_chain_1_s0/CLK
4.464 | 0.331 | tC2Q | RF | 12951 | R73C54[1][A] | u_rst_sync/sync_chain_1_s0/Q
6.487 | 2.023 | tNET | FF | 1 | R46C22[3][B] | g_sound.u_looper/on_addr_r[9]_0_s0/CLEAR

Data Required Path:

AT | DELAY | TYPE | RF | FANOUT | LOC | NODE
20.000 | 20.000 | | | | | active clock edge time
20.000 | 0.000 | | | | | clk_sys
20.000 | 0.000 | tCL | RR | 1 | IOB117[B] | clk_ibuf/I
21.288 | 1.288 | tINS | RR | 15774 | IOB117[B] | clk_ibuf/O
24.133 | 2.845 | tNET | RR | 1 | R46C22[3][B] | g_sound.u_looper/on_addr_r[9]_0_s0/CLK
23.821 | -0.313 | tSu | | 1 | R46C22[3][B] | g_sound.u_looper/on_addr_r[9]_0_s0

Path Statistics:

Clock Skew | 0.000
Setup Relationship | 20.000
Logic Level | 1
Arrival Clock Path Delay | cell: 1.288, 31.169%; route: 2.845, 68.831%
Arrival Data Path Delay | cell: 0.000, 0.000%; route: 2.023, 85.946%; tC2Q: 0.331, 14.054%
Required Clock Path Delay | cell: 1.288, 31.169%; route: 2.845, 68.831%

### Path13

Path Summary:

Slack | 17.334
Data Arrival Time | 6.487
Data Required Time | 23.821
From | u_rst_sync/sync_chain_1_s0
To | g_sound.u_looper/last_inc_r[13]_14_s0
Launch Clk | clk_sys:[R]
Latch Clk | clk_sys:[R]

Data Arrival Path:

AT | DELAY | TYPE | RF | FANOUT | LOC | NODE
0.000 | 0.000 | | | | | active clock edge time
0.000 | 0.000 | | | | | clk_sys
0.000 | 0.000 | tCL | RR | 1 | IOB117[B] | clk_ibuf/I
1.288 | 1.288 | tINS | RR | 15774 | IOB117[B] | clk_ibuf/O
4.133 | 2.845 | tNET | RR | 1 | R73C54[1][A] | u_rst_sync/sync_chain_1_s0/CLK
4.464 | 0.331 | tC2Q | RF | 12951 | R73C54[1][A] | u_rst_sync/sync_chain_1_s0/Q
6.487 | 2.023 | tNET | FF | 1 | R46C18[0][B] | g_sound.u_looper/last_inc_r[13]_14_s0/CLEAR

Data Required Path:

AT | DELAY | TYPE | RF | FANOUT | LOC | NODE
20.000 | 20.000 | | | | | active clock edge time
20.000 | 0.000 | | | | | clk_sys
20.000 | 0.000 | tCL | RR | 1 | IOB117[B] | clk_ibuf/I
21.288 | 1.288 | tINS | RR | 15774 | IOB117[B] | clk_ibuf/O
24.133 | 2.845 | tNET | RR | 1 | R46C18[0][B] | g_sound.u_looper/last_inc_r[13]_14_s0/CLK
23.821 | -0.313 | tSu | | 1 | R46C18[0][B] | g_sound.u_looper/last_inc_r[13]_14_s0

Path Statistics:

Clock Skew | 0.000
Setup Relationship | 20.000
Logic Level | 1
Arrival Clock Path Delay | cell: 1.288, 31.169%; route: 2.845, 68.831%
Arrival Data Path Delay | cell: 0.000, 0.000%; route: 2.023, 85.946%; tC2Q: 0.331, 14.054%
Required Clock Path Delay | cell: 1.288, 31.169%; route: 2.845, 68.831%

### Path14

Path Summary:

Slack | 17.334
Data Arrival Time | 6.487
Data Required Time | 23.821
From | u_rst_sync/sync_chain_1_s0
To | g_sound.u_looper/last_inc_r[5]_11_s0
Launch Clk | clk_sys:[R]
Latch Clk | clk_sys:[R]

Data Arrival Path:

AT | DELAY | TYPE | RF | FANOUT | LOC | NODE
0.000 | 0.000 | | | | | active clock edge time
0.000 | 0.000 | | | | | clk_sys
0.000 | 0.000 | tCL | RR | 1 | IOB117[B] | clk_ibuf/I
1.288 | 1.288 | tINS | RR | 15774 | IOB117[B] | clk_ibuf/O
4.133 | 2.845 | tNET | RR | 1 | R73C54[1][A] | u_rst_sync/sync_chain_1_s0/CLK
4.464 | 0.331 | tC2Q | RF | 12951 | R73C54[1][A] | u_rst_sync/sync_chain_1_s0/Q
6.487 | 2.023 | tNET | FF | 1 | R46C18[1][A] | g_sound.u_looper/last_inc_r[5]_11_s0/CLEAR

Data Required Path:

AT | DELAY | TYPE | RF | FANOUT | LOC | NODE
20.000 | 20.000 | | | | | active clock edge time
20.000 | 0.000 | | | | | clk_sys
20.000 | 0.000 | tCL | RR | 1 | IOB117[B] | clk_ibuf/I
21.288 | 1.288 | tINS | RR | 15774 | IOB117[B] | clk_ibuf/O
24.133 | 2.845 | tNET | RR | 1 | R46C18[1][A] | g_sound.u_looper/last_inc_r[5]_11_s0/CLK
23.821 | -0.313 | tSu | | 1 | R46C18[1][A] | g_sound.u_looper/last_inc_r[5]_11_s0

Path Statistics:

Clock Skew | 0.000
Setup Relationship | 20.000
Logic Level | 1
Arrival Clock Path Delay | cell: 1.288, 31.169%; route: 2.845, 68.831%
Arrival Data Path Delay | cell: 0.000, 0.000%; route: 2.023, 85.946%; tC2Q: 0.331, 14.054%
Required Clock Path Delay | cell: 1.288, 31.169%; route: 2.845, 68.831%

### Path15

Path Summary:

Slack | 17.334
Data Arrival Time | 6.487
Data Required Time | 23.821
From | u_rst_sync/sync_chain_1_s0
To | g_sound.u_looper/last_inc_r[5]_14_s0
Launch Clk | clk_sys:[R]
Latch Clk | clk_sys:[R]

Data Arrival Path:

AT | DELAY | TYPE | RF | FANOUT | LOC | NODE
0.000 | 0.000 | | | | | active clock edge time
0.000 | 0.000 | | | | | clk_sys
0.000 | 0.000 | tCL | RR | 1 | IOB117[B] | clk_ibuf/I
1.288 | 1.288 | tINS | RR | 15774 | IOB117[B] | clk_ibuf/O
4.133 | 2.845 | tNET | RR | 1 | R73C54[1][A] | u_rst_sync/sync_chain_1_s0/CLK
4.464 | 0.331 | tC2Q | RF | 12951 | R73C54[1][A] | u_rst_sync/sync_chain_1_s0/Q
6.487 | 2.023 | tNET | FF | 1 | R46C18[1][B] | g_sound.u_looper/last_inc_r[5]_14_s0/CLEAR

Data Required Path:

AT | DELAY | TYPE | RF | FANOUT | LOC | NODE
20.000 | 20.000 | | | | | active clock edge time
20.000 | 0.000 | | | | | clk_sys
20.000 | 0.000 | tCL | RR | 1 | IOB117[B] | clk_ibuf/I
21.288 | 1.288 | tINS | RR | 15774 | IOB117[B] | clk_ibuf/O
24.133 | 2.845 | tNET | RR | 1 | R46C18[1][B] | g_sound.u_looper/last_inc_r[5]_14_s0/CLK
23.821 | -0.313 | tSu | | 1 | R46C18[1][B] | g_sound.u_looper/last_inc_r[5]_14_s0

Path Statistics:

Clock Skew | 0.000
Setup Relationship | 20.000
Logic Level | 1
Arrival Clock Path Delay | cell: 1.288, 31.169%; route: 2.845, 68.831%
Arrival Data Path Delay | cell: 0.000, 0.000%; route: 2.023, 85.946%; tC2Q: 0.331, 14.054%
Required Clock Path Delay | cell: 1.288, 31.169%; route: 2.845, 68.831%

### Path16

Path Summary:

Slack | 17.334
Data Arrival Time | 6.487
Data Required Time | 23.821
From | u_rst_sync/sync_chain_1_s0
To | g_sound.u_looper/last_inc_r[0]_11_s0
Launch Clk | clk_sys:[R]
Latch Clk | clk_sys:[R]

Data Arrival Path:

AT | DELAY | TYPE | RF | FANOUT | LOC | NODE
0.000 | 0.000 | | | | | active clock edge time
0.000 | 0.000 | | | | | clk_sys
0.000 | 0.000 | tCL | RR | 1 | IOB117[B] | clk_ibuf/I
1.288 | 1.288 | tINS | RR | 15774 | IOB117[B] | clk_ibuf/O
4.133 | 2.845 | tNET | RR | 1 | R73C54[1][A] | u_rst_sync/sync_chain_1_s0/CLK
4.464 | 0.331 | tC2Q | RF | 12951 | R73C54[1][A] | u_rst_sync/sync_chain_1_s0/Q
6.487 | 2.023 | tNET | FF | 1 | R46C18[2][A] | g_sound.u_looper/last_inc_r[0]_11_s0/CLEAR

Data Required Path:

AT | DELAY | TYPE | RF | FANOUT | LOC | NODE
20.000 | 20.000 | | | | | active clock edge time
20.000 | 0.000 | | | | | clk_sys
20.000 | 0.000 | tCL | RR | 1 | IOB117[B] | clk_ibuf/I
21.288 | 1.288 | tINS | RR | 15774 | IOB117[B] | clk_ibuf/O
24.133 | 2.845 | tNET | RR | 1 | R46C18[2][A] | g_sound.u_looper/last_inc_r[0]_11_s0/CLK
23.821 | -0.313 | tSu | | 1 | R46C18[2][A] | g_sound.u_looper/last_inc_r[0]_11_s0

Path Statistics:

Clock Skew | 0.000
Setup Relationship | 20.000
Logic Level | 1
Arrival Clock Path Delay | cell: 1.288, 31.169%; route: 2.845, 68.831%
Arrival Data Path Delay | cell: 0.000, 0.000%; route: 2.023, 85.946%; tC2Q: 0.331, 14.054%
Required Clock Path Delay | cell: 1.288, 31.169%; route: 2.845, 68.831%

### Path17

Path Summary:

Slack | 17.334
Data Arrival Time | 6.487
Data Required Time | 23.821
From | u_rst_sync/sync_chain_1_s0
To | g_sound.u_looper/last_inc_r[0]_12_s0
Launch Clk | clk_sys:[R]
Latch Clk | clk_sys:[R]

Data Arrival Path:

AT | DELAY | TYPE | RF | FANOUT | LOC | NODE
0.000 | 0.000 | | | | | active clock edge time
0.000 | 0.000 | | | | | clk_sys
0.000 | 0.000 | tCL | RR | 1 | IOB117[B] | clk_ibuf/I
1.288 | 1.288 | tINS | RR | 15774 | IOB117[B] | clk_ibuf/O
4.133 | 2.845 | tNET | RR | 1 | R73C54[1][A] | u_rst_sync/sync_chain_1_s0/CLK
4.464 | 0.331 | tC2Q | RF | 12951 | R73C54[1][A] | u_rst_sync/sync_chain_1_s0/Q
6.487 | 2.023 | tNET | FF | 1 | R46C18[2][B] | g_sound.u_looper/last_inc_r[0]_12_s0/CLEAR

Data Required Path:

AT | DELAY | TYPE | RF | FANOUT | LOC | NODE
20.000 | 20.000 | | | | | active clock edge time
20.000 | 0.000 | | | | | clk_sys
20.000 | 0.000 | tCL | RR | 1 | IOB117[B] | clk_ibuf/I
21.288 | 1.288 | tINS | RR | 15774 | IOB117[B] | clk_ibuf/O
24.133 | 2.845 | tNET | RR | 1 | R46C18[2][B] | g_sound.u_looper/last_inc_r[0]_12_s0/CLK
23.821 | -0.313 | tSu | | 1 | R46C18[2][B] | g_sound.u_looper/last_inc_r[0]_12_s0

Path Statistics:

Clock Skew | 0.000
Setup Relationship | 20.000
Logic Level | 1
Arrival Clock Path Delay | cell: 1.288, 31.169%; route: 2.845, 68.831%
Arrival Data Path Delay | cell: 0.000, 0.000%; route: 2.023, 85.946%; tC2Q: 0.331, 14.054%
Required Clock Path Delay | cell: 1.288, 31.169%; route: 2.845, 68.831%

### Path18

Path Summary:

Slack | 17.334
Data Arrival Time | 6.487
Data Required Time | 23.821
From | u_rst_sync/sync_chain_1_s0
To | g_sound.u_looper/last_inc_r[0]_13_s0
Launch Clk | clk_sys:[R]
Latch Clk | clk_sys:[R]

Data Arrival Path:

AT | DELAY | TYPE | RF | FANOUT | LOC | NODE
0.000 | 0.000 | | | | | active clock edge time
0.000 | 0.000 | | | | | clk_sys
0.000 | 0.000 | tCL | RR | 1 | IOB117[B] | clk_ibuf/I
1.288 | 1.288 | tINS | RR | 15774 | IOB117[B] | clk_ibuf/O
4.133 | 2.845 | tNET | RR | 1 | R73C54[1][A] | u_rst_sync/sync_chain_1_s0/CLK
4.464 | 0.331 | tC2Q | RF | 12951 | R73C54[1][A] | u_rst_sync/sync_chain_1_s0/Q
6.487 | 2.023 | tNET | FF | 1 | R46C18[3][A] | g_sound.u_looper/last_inc_r[0]_13_s0/CLEAR

Data Required Path:

AT | DELAY | TYPE | RF | FANOUT | LOC | NODE
20.000 | 20.000 | | | | | active clock edge time
20.000 | 0.000 | | | | | clk_sys
20.000 | 0.000 | tCL | RR | 1 | IOB117[B] | clk_ibuf/I
21.288 | 1.288 | tINS | RR | 15774 | IOB117[B] | clk_ibuf/O
24.133 | 2.845 | tNET | RR | 1 | R46C18[3][A] | g_sound.u_looper/last_inc_r[0]_13_s0/CLK
23.821 | -0.313 | tSu | | 1 | R46C18[3][A] | g_sound.u_looper/last_inc_r[0]_13_s0

Path Statistics:

Clock Skew | 0.000
Setup Relationship | 20.000
Logic Level | 1
Arrival Clock Path Delay | cell: 1.288, 31.169%; route: 2.845, 68.831%
Arrival Data Path Delay | cell: 0.000, 0.000%; route: 2.023, 85.946%; tC2Q: 0.331, 14.054%
Required Clock Path Delay | cell: 1.288, 31.169%; route: 2.845, 68.831%

### Path19

Path Summary:

Slack | 17.334
Data Arrival Time | 6.487
Data Required Time | 23.821
From | u_rst_sync/sync_chain_1_s0
To | g_sound.u_looper/play_inc_o_1_s0
Launch Clk | clk_sys:[R]
Latch Clk | clk_sys:[R]

Data Arrival Path:

AT | DELAY | TYPE | RF | FANOUT | LOC | NODE
0.000 | 0.000 | | | | | active clock edge time
0.000 | 0.000 | | | | | clk_sys
0.000 | 0.000 | tCL | RR | 1 | IOB117[B] | clk_ibuf/I
1.288 | 1.288 | tINS | RR | 15774 | IOB117[B] | clk_ibuf/O
4.133 | 2.845 | tNET | RR | 1 | R73C54[1][A] | u_rst_sync/sync_chain_1_s0/CLK
4.464 | 0.331 | tC2Q | RF | 12951 | R73C54[1][A] | u_rst_sync/sync_chain_1_s0/Q
6.487 | 2.023 | tNET | FF | 1 | R46C6[1][B] | g_sound.u_looper/play_inc_o_1_s0/CLEAR

Data Required Path:

AT | DELAY | TYPE | RF | FANOUT | LOC | NODE
20.000 | 20.000 | | | | | active clock edge time
20.000 | 0.000 | | | | | clk_sys
20.000 | 0.000 | tCL | RR | 1 | IOB117[B] | clk_ibuf/I
21.288 | 1.288 | tINS | RR | 15774 | IOB117[B] | clk_ibuf/O
24.133 | 2.845 | tNET | RR | 1 | R46C6[1][B] | g_sound.u_looper/play_inc_o_1_s0/CLK
23.821 | -0.313 | tSu | | 1 | R46C6[1][B] | g_sound.u_looper/play_inc_o_1_s0

Path Statistics:

Clock Skew | 0.000
Setup Relationship | 20.000
Logic Level | 1
Arrival Clock Path Delay | cell: 1.288, 31.169%; route: 2.845, 68.831%
Arrival Data Path Delay | cell: 0.000, 0.000%; route: 2.023, 85.946%; tC2Q: 0.331, 14.054%
Required Clock Path Delay | cell: 1.288, 31.169%; route: 2.845, 68.831%

### Path20

Path Summary:

Slack | 17.334
Data Arrival Time | 6.487
Data Required Time | 23.821
From | u_rst_sync/sync_chain_1_s0
To | g_sound.u_looper/play_inc_o_5_s0
Launch Clk | clk_sys:[R]
Latch Clk | clk_sys:[R]

Data Arrival Path:

AT | DELAY | TYPE | RF | FANOUT | LOC | NODE
0.000 | 0.000 | | | | | active clock edge time
0.000 | 0.000 | | | | | clk_sys
0.000 | 0.000 | tCL | RR | 1 | IOB117[B] | clk_ibuf/I
1.288 | 1.288 | tINS | RR | 15774 | IOB117[B] | clk_ibuf/O
4.133 | 2.845 | tNET | RR | 1 | R73C54[1][A] | u_rst_sync/sync_chain_1_s0/CLK
4.464 | 0.331 | tC2Q | RF | 12951 | R73C54[1][A] | u_rst_sync/sync_chain_1_s0/Q
6.487 | 2.023 | tNET | FF | 1 | R46C6[0][B] | g_sound.u_looper/play_inc_o_5_s0/CLEAR

Data Required Path:

AT | DELAY | TYPE | RF | FANOUT | LOC | NODE
20.000 | 20.000 | | | | | active clock edge time
20.000 | 0.000 | | | | | clk_sys
20.000 | 0.000 | tCL | RR | 1 | IOB117[B] | clk_ibuf/I
21.288 | 1.288 | tINS | RR | 15774 | IOB117[B] | clk_ibuf/O
24.133 | 2.845 | tNET | RR | 1 | R46C6[0][B] | g_sound.u_looper/play_inc_o_5_s0/CLK
23.821 | -0.313 | tSu | | 1 | R46C6[0][B] | g_sound.u_looper/play_inc_o_5_s0

Path Statistics:

Clock Skew | 0.000
Setup Relationship | 20.000
Logic Level | 1
Arrival Clock Path Delay | cell: 1.288, 31.169%; route: 2.845, 68.831%
Arrival Data Path Delay | cell: 0.000, 0.000%; route: 2.023, 85.946%; tC2Q: 0.331, 14.054%
Required Clock Path Delay | cell: 1.288, 31.169%; route: 2.845, 68.831%

### Path21

Path Summary:

Slack | 17.334
Data Arrival Time | 6.487
Data Required Time | 23.821
From | u_rst_sync/sync_chain_1_s0
To | g_sound.u_looper/play_inc_o_11_s0
Launch Clk | clk_sys:[R]
Latch Clk | clk_sys:[R]

Data Arrival Path:

AT | DELAY | TYPE | RF | FANOUT | LOC | NODE
0.000 | 0.000 | | | | | active clock edge time
0.000 | 0.000 | | | | | clk_sys
0.000 | 0.000 | tCL | RR | 1 | IOB117[B] | clk_ibuf/I
1.288 | 1.288 | tINS | RR | 15774 | IOB117[B] | clk_ibuf/O
4.133 | 2.845 | tNET | RR | 1 | R73C54[1][A] | u_rst_sync/sync_chain_1_s0/CLK
4.464 | 0.331 | tC2Q | RF | 12951 | R73C54[1][A] | u_rst_sync/sync_chain_1_s0/Q
6.487 | 2.023 | tNET | FF | 1 | R46C6[1][A] | g_sound.u_looper/play_inc_o_11_s0/CLEAR

Data Required Path:

AT | DELAY | TYPE | RF | FANOUT | LOC | NODE
20.000 | 20.000 | | | | | active clock edge time
20.000 | 0.000 | | | | | clk_sys
20.000 | 0.000 | tCL | RR | 1 | IOB117[B] | clk_ibuf/I
21.288 | 1.288 | tINS | RR | 15774 | IOB117[B] | clk_ibuf/O
24.133 | 2.845 | tNET | RR | 1 | R46C6[1][A] | g_sound.u_looper/play_inc_o_11_s0/CLK
23.821 | -0.313 | tSu | | 1 | R46C6[1][A] | g_sound.u_looper/play_inc_o_11_s0

Path Statistics:

Clock Skew | 0.000
Setup Relationship | 20.000
Logic Level | 1
Arrival Clock Path Delay | cell: 1.288, 31.169%; route: 2.845, 68.831%
Arrival Data Path Delay | cell: 0.000, 0.000%; route: 2.023, 85.946%; tC2Q: 0.331, 14.054%
Required Clock Path Delay | cell: 1.288, 31.169%; route: 2.845, 68.831%

### Path22

Path Summary:

Slack | 17.334
Data Arrival Time | 6.487
Data Required Time | 23.821
From | u_rst_sync/sync_chain_1_s0
To | g_sound.u_looper/play_inc_o_14_s0
Launch Clk | clk_sys:[R]
Latch Clk | clk_sys:[R]

Data Arrival Path:

AT | DELAY | TYPE | RF | FANOUT | LOC | NODE
0.000 | 0.000 | | | | | active clock edge time
0.000 | 0.000 | | | | | clk_sys
0.000 | 0.000 | tCL | RR | 1 | IOB117[B] | clk_ibuf/I
1.288 | 1.288 | tINS | RR | 15774 | IOB117[B] | clk_ibuf/O
4.133 | 2.845 | tNET | RR | 1 | R73C54[1][A] | u_rst_sync/sync_chain_1_s0/CLK
4.464 | 0.331 | tC2Q | RF | 12951 | R73C54[1][A] | u_rst_sync/sync_chain_1_s0/Q
6.487 | 2.023 | tNET | FF | 1 | R46C6[0][A] | g_sound.u_looper/play_inc_o_14_s0/CLEAR

Data Required Path:

AT | DELAY | TYPE | RF | FANOUT | LOC | NODE
20.000 | 20.000 | | | | | active clock edge time
20.000 | 0.000 | | | | | clk_sys
20.000 | 0.000 | tCL | RR | 1 | IOB117[B] | clk_ibuf/I
21.288 | 1.288 | tINS | RR | 15774 | IOB117[B] | clk_ibuf/O
24.133 | 2.845 | tNET | RR | 1 | R46C6[0][A] | g_sound.u_looper/play_inc_o_14_s0/CLK
23.821 | -0.313 | tSu | | 1 | R46C6[0][A] | g_sound.u_looper/play_inc_o_14_s0

Path Statistics:

Clock Skew | 0.000
Setup Relationship | 20.000
Logic Level | 1
Arrival Clock Path Delay | cell: 1.288, 31.169%; route: 2.845, 68.831%
Arrival Data Path Delay | cell: 0.000, 0.000%; route: 2.023, 85.946%; tC2Q: 0.331, 14.054%
Required Clock Path Delay | cell: 1.288, 31.169%; route: 2.845, 68.831%

### Path23

Path Summary:

Slack | 17.334
Data Arrival Time | 6.487
Data Required Time | 23.821
From | u_rst_sync/sync_chain_1_s0
To | g_sound.u_looper/play_inc_o_19_s0
Launch Clk | clk_sys:[R]
Latch Clk | clk_sys:[R]

Data Arrival Path:

AT | DELAY | TYPE | RF | FANOUT | LOC | NODE
0.000 | 0.000 | | | | | active clock edge time
0.000 | 0.000 | | | | | clk_sys
0.000 | 0.000 | tCL | RR | 1 | IOB117[B] | clk_ibuf/I
1.288 | 1.288 | tINS | RR | 15774 | IOB117[B] | clk_ibuf/O
4.133 | 2.845 | tNET | RR | 1 | R73C54[1][A] | u_rst_sync/sync_chain_1_s0/CLK
4.464 | 0.331 | tC2Q | RF | 12951 | R73C54[1][A] | u_rst_sync/sync_chain_1_s0/Q
6.487 | 2.023 | tNET | FF | 1 | R46C6[3][A] | g_sound.u_looper/play_inc_o_19_s0/CLEAR

Data Required Path:

AT | DELAY | TYPE | RF | FANOUT | LOC | NODE
20.000 | 20.000 | | | | | active clock edge time
20.000 | 0.000 | | | | | clk_sys
20.000 | 0.000 | tCL | RR | 1 | IOB117[B] | clk_ibuf/I
21.288 | 1.288 | tINS | RR | 15774 | IOB117[B] | clk_ibuf/O
24.133 | 2.845 | tNET | RR | 1 | R46C6[3][A] | g_sound.u_looper/play_inc_o_19_s0/CLK
23.821 | -0.313 | tSu | | 1 | R46C6[3][A] | g_sound.u_looper/play_inc_o_19_s0

Path Statistics:

Clock Skew | 0.000
Setup Relationship | 20.000
Logic Level | 1
Arrival Clock Path Delay | cell: 1.288, 31.169%; route: 2.845, 68.831%
Arrival Data Path Delay | cell: 0.000, 0.000%; route: 2.023, 85.946%; tC2Q: 0.331, 14.054%
Required Clock Path Delay | cell: 1.288, 31.169%; route: 2.845, 68.831%

### Path24

Path Summary:

Slack | 17.334
Data Arrival Time | 6.487
Data Required Time | 23.821
From | u_rst_sync/sync_chain_1_s0
To | g_sound.u_looper/play_inc_o_20_s0
Launch Clk | clk_sys:[R]
Latch Clk | clk_sys:[R]

Data Arrival Path:

AT | DELAY | TYPE | RF | FANOUT | LOC | NODE
0.000 | 0.000 | | | | | active clock edge time
0.000 | 0.000 | | | | | clk_sys
0.000 | 0.000 | tCL | RR | 1 | IOB117[B] | clk_ibuf/I
1.288 | 1.288 | tINS | RR | 15774 | IOB117[B] | clk_ibuf/O
4.133 | 2.845 | tNET | RR | 1 | R73C54[1][A] | u_rst_sync/sync_chain_1_s0/CLK
4.464 | 0.331 | tC2Q | RF | 12951 | R73C54[1][A] | u_rst_sync/sync_chain_1_s0/Q
6.487 | 2.023 | tNET | FF | 1 | R46C6[2][B] | g_sound.u_looper/play_inc_o_20_s0/CLEAR

Data Required Path:

AT | DELAY | TYPE | RF | FANOUT | LOC | NODE
20.000 | 20.000 | | | | | active clock edge time
20.000 | 0.000 | | | | | clk_sys
20.000 | 0.000 | tCL | RR | 1 | IOB117[B] | clk_ibuf/I
21.288 | 1.288 | tINS | RR | 15774 | IOB117[B] | clk_ibuf/O
24.133 | 2.845 | tNET | RR | 1 | R46C6[2][B] | g_sound.u_looper/play_inc_o_20_s0/CLK
23.821 | -0.313 | tSu | | 1 | R46C6[2][B] | g_sound.u_looper/play_inc_o_20_s0

Path Statistics:

Clock Skew | 0.000
Setup Relationship | 20.000
Logic Level | 1
Arrival Clock Path Delay | cell: 1.288, 31.169%; route: 2.845, 68.831%
Arrival Data Path Delay | cell: 0.000, 0.000%; route: 2.023, 85.946%; tC2Q: 0.331, 14.054%
Required Clock Path Delay | cell: 1.288, 31.169%; route: 2.845, 68.831%

### Path25

Path Summary:

Slack | 17.334
Data Arrival Time | 6.487
Data Required Time | 23.821
From | u_rst_sync/sync_chain_1_s0
To | g_sound.u_looper/play_inc_o_21_s0
Launch Clk | clk_sys:[R]
Latch Clk | clk_sys:[R]

Data Arrival Path:

AT | DELAY | TYPE | RF | FANOUT | LOC | NODE
0.000 | 0.000 | | | | | active clock edge time
0.000 | 0.000 | | | | | clk_sys
0.000 | 0.000 | tCL | RR | 1 | IOB117[B] | clk_ibuf/I
1.288 | 1.288 | tINS | RR | 15774 | IOB117[B] | clk_ibuf/O
4.133 | 2.845 | tNET | RR | 1 | R73C54[1][A] | u_rst_sync/sync_chain_1_s0/CLK
4.464 | 0.331 | tC2Q | RF | 12951 | R73C54[1][A] | u_rst_sync/sync_chain_1_s0/Q
6.487 | 2.023 | tNET | FF | 1 | R46C6[2][A] | g_sound.u_looper/play_inc_o_21_s0/CLEAR

Data Required Path:

AT | DELAY | TYPE | RF | FANOUT | LOC | NODE
20.000 | 20.000 | | | | | active clock edge time
20.000 | 0.000 | | | | | clk_sys
20.000 | 0.000 | tCL | RR | 1 | IOB117[B] | clk_ibuf/I
21.288 | 1.288 | tINS | RR | 15774 | IOB117[B] | clk_ibuf/O
24.133 | 2.845 | tNET | RR | 1 | R46C6[2][A] | g_sound.u_looper/play_inc_o_21_s0/CLK
23.821 | -0.313 | tSu | | 1 | R46C6[2][A] | g_sound.u_looper/play_inc_o_21_s0

Path Statistics:

Clock Skew | 0.000
Setup Relationship | 20.000
Logic Level | 1
Arrival Clock Path Delay | cell: 1.288, 31.169%; route: 2.845, 68.831%
Arrival Data Path Delay | cell: 0.000, 0.000%; route: 2.023, 85.946%; tC2Q: 0.331, 14.054%
Required Clock Path Delay | cell: 1.288, 31.169%; route: 2.845, 68.831%

### Removal Analysis Report

#### Report Command:report_timing -removal -max_paths 25 -max_common_paths 1

### Path1

Path Summary:

Slack | 0.223
Data Arrival Time | 43.194
Data Required Time | 42.971
From | u_rst_sync/sync_chain_1_s0
To | u_hdmi/u_serializer/lanes[3].u_oser
Launch Clk | clk_sys:[R]
Latch Clk | pixel_clk:[R]

Data Arrival Path:

AT | DELAY | TYPE | RF | FANOUT | LOC | NODE
40.000 | 40.000 | | | | | active clock edge time
40.000 | 0.000 | | | | | clk_sys
40.000 | 0.000 | tCL | RR | 1 | IOB117[B] | clk_ibuf/I
40.952 | 0.952 | tINS | RR | 15774 | IOB117[B] | clk_ibuf/O
42.186 | 1.234 | tNET | RR | 1 | R73C54[1][A] | u_rst_sync/sync_chain_1_s0/CLK
42.316 | 0.130 | tC2Q | RR | 12951 | R73C54[1][A] | u_rst_sync/sync_chain_1_s0/Q
43.194 | 0.878 | tNET | RR | 1 | IOR24[A] | u_hdmi/u_serializer/lanes[3].u_oser/RESET

Data Required Path:

AT | DELAY | TYPE | RF | FANOUT | LOC | NODE
40.000 | 40.000 | | | | | active clock edge time
40.000 | 0.000 | | | | | pixel_clk
42.186 | 2.186 | tCL | RR | 154 | PLL_R[1] | u_hdmi/u_clk/u_pll/CLKOUT1
42.799 | 0.612 | tNET | RR | 1 | IOR24[A] | u_hdmi/u_serializer/lanes[3].u_oser/PCLK
42.834 | 0.035 | tUnc
42.971 | 0.138 | tHld | | 1 | IOR24[A] | u_hdmi/u_serializer/lanes[3].u_oser

Path Statistics:

Clock Skew | 0.612
Hold Relationship | 0.000
Logic Level | 1
Arrival Clock Path Delay | cell: 0.952, 43.558%; route: 1.234, 56.442%
Arrival Data Path Delay | cell: 0.000, 0.000%; route: 0.878, 87.143%; tC2Q: 0.130, 12.857%
Required Clock Path Delay | cell: 0.000, 0.000%; route: 0.612, 100.000%

### Path2

Path Summary:

Slack | 0.223
Data Arrival Time | 43.194
Data Required Time | 42.971
From | u_rst_sync/sync_chain_1_s0
To | u_hdmi/u_serializer/lanes[2].u_oser
Launch Clk | clk_sys:[R]
Latch Clk | pixel_clk:[R]

Data Arrival Path:

AT | DELAY | TYPE | RF | FANOUT | LOC | NODE
40.000 | 40.000 | | | | | active clock edge time
40.000 | 0.000 | | | | | clk_sys
40.000 | 0.000 | tCL | RR | 1 | IOB117[B] | clk_ibuf/I
40.952 | 0.952 | tINS | RR | 15774 | IOB117[B] | clk_ibuf/O
42.186 | 1.234 | tNET | RR | 1 | R73C54[1][A] | u_rst_sync/sync_chain_1_s0/CLK
42.316 | 0.130 | tC2Q | RR | 12951 | R73C54[1][A] | u_rst_sync/sync_chain_1_s0/Q
43.194 | 0.878 | tNET | RR | 1 | IOR39[A] | u_hdmi/u_serializer/lanes[2].u_oser/RESET

Data Required Path:

AT | DELAY | TYPE | RF | FANOUT | LOC | NODE
40.000 | 40.000 | | | | | active clock edge time
40.000 | 0.000 | | | | | pixel_clk
42.186 | 2.186 | tCL | RR | 154 | PLL_R[1] | u_hdmi/u_clk/u_pll/CLKOUT1
42.799 | 0.612 | tNET | RR | 1 | IOR39[A] | u_hdmi/u_serializer/lanes[2].u_oser/PCLK
42.834 | 0.035 | tUnc
42.971 | 0.138 | tHld | | 1 | IOR39[A] | u_hdmi/u_serializer/lanes[2].u_oser

Path Statistics:

Clock Skew | 0.612
Hold Relationship | 0.000
Logic Level | 1
Arrival Clock Path Delay | cell: 0.952, 43.558%; route: 1.234, 56.442%
Arrival Data Path Delay | cell: 0.000, 0.000%; route: 0.878, 87.143%; tC2Q: 0.130, 12.857%
Required Clock Path Delay | cell: 0.000, 0.000%; route: 0.612, 100.000%

### Path3

Path Summary:

Slack | 0.223
Data Arrival Time | 43.194
Data Required Time | 42.971
From | u_rst_sync/sync_chain_1_s0
To | u_hdmi/u_serializer/lanes[1].u_oser
Launch Clk | clk_sys:[R]
Latch Clk | pixel_clk:[R]

Data Arrival Path:

AT | DELAY | TYPE | RF | FANOUT | LOC | NODE
40.000 | 40.000 | | | | | active clock edge time
40.000 | 0.000 | | | | | clk_sys
40.000 | 0.000 | tCL | RR | 1 | IOB117[B] | clk_ibuf/I
40.952 | 0.952 | tINS | RR | 15774 | IOB117[B] | clk_ibuf/O
42.186 | 1.234 | tNET | RR | 1 | R73C54[1][A] | u_rst_sync/sync_chain_1_s0/CLK
42.316 | 0.130 | tC2Q | RR | 12951 | R73C54[1][A] | u_rst_sync/sync_chain_1_s0/Q
43.194 | 0.878 | tNET | RR | 1 | IOR22[A] | u_hdmi/u_serializer/lanes[1].u_oser/RESET

Data Required Path:

AT | DELAY | TYPE | RF | FANOUT | LOC | NODE
40.000 | 40.000 | | | | | active clock edge time
40.000 | 0.000 | | | | | pixel_clk
42.186 | 2.186 | tCL | RR | 154 | PLL_R[1] | u_hdmi/u_clk/u_pll/CLKOUT1
42.799 | 0.612 | tNET | RR | 1 | IOR22[A] | u_hdmi/u_serializer/lanes[1].u_oser/PCLK
42.834 | 0.035 | tUnc
42.971 | 0.138 | tHld | | 1 | IOR22[A] | u_hdmi/u_serializer/lanes[1].u_oser

Path Statistics:

Clock Skew | 0.612
Hold Relationship | 0.000
Logic Level | 1
Arrival Clock Path Delay | cell: 0.952, 43.558%; route: 1.234, 56.442%
Arrival Data Path Delay | cell: 0.000, 0.000%; route: 0.878, 87.143%; tC2Q: 0.130, 12.857%
Required Clock Path Delay | cell: 0.000, 0.000%; route: 0.612, 100.000%

### Path4

Path Summary:

Slack | 0.223
Data Arrival Time | 43.194
Data Required Time | 42.971
From | u_rst_sync/sync_chain_1_s0
To | u_hdmi/u_serializer/lanes[0].u_oser
Launch Clk | clk_sys:[R]
Latch Clk | pixel_clk:[R]

Data Arrival Path:

AT | DELAY | TYPE | RF | FANOUT | LOC | NODE
40.000 | 40.000 | | | | | active clock edge time
40.000 | 0.000 | | | | | clk_sys
40.000 | 0.000 | tCL | RR | 1 | IOB117[B] | clk_ibuf/I
40.952 | 0.952 | tINS | RR | 15774 | IOB117[B] | clk_ibuf/O
42.186 | 1.234 | tNET | RR | 1 | R73C54[1][A] | u_rst_sync/sync_chain_1_s0/CLK
42.316 | 0.130 | tC2Q | RR | 12951 | R73C54[1][A] | u_rst_sync/sync_chain_1_s0/Q
43.194 | 0.878 | tNET | RR | 1 | IOR26[A] | u_hdmi/u_serializer/lanes[0].u_oser/RESET

Data Required Path:

AT | DELAY | TYPE | RF | FANOUT | LOC | NODE
40.000 | 40.000 | | | | | active clock edge time
40.000 | 0.000 | | | | | pixel_clk
42.186 | 2.186 | tCL | RR | 154 | PLL_R[1] | u_hdmi/u_clk/u_pll/CLKOUT1
42.799 | 0.612 | tNET | RR | 1 | IOR26[A] | u_hdmi/u_serializer/lanes[0].u_oser/PCLK
42.834 | 0.035 | tUnc
42.971 | 0.138 | tHld | | 1 | IOR26[A] | u_hdmi/u_serializer/lanes[0].u_oser

Path Statistics:

Clock Skew | 0.612
Hold Relationship | 0.000
Logic Level | 1
Arrival Clock Path Delay | cell: 0.952, 43.558%; route: 1.234, 56.442%
Arrival Data Path Delay | cell: 0.000, 0.000%; route: 0.878, 87.143%; tC2Q: 0.130, 12.857%
Required Clock Path Delay | cell: 0.000, 0.000%; route: 0.612, 100.000%

### Path5

Path Summary:

Slack | 0.408
Data Arrival Time | 43.191
Data Required Time | 42.783
From | u_rst_sync/sync_chain_1_s0
To | u_hdmi/reset_pipe_1_s0
Launch Clk | clk_sys:[R]
Latch Clk | pixel_clk:[R]

Data Arrival Path:

AT | DELAY | TYPE | RF | FANOUT | LOC | NODE
40.000 | 40.000 | | | | | active clock edge time
40.000 | 0.000 | | | | | clk_sys
40.000 | 0.000 | tCL | RR | 1 | IOB117[B] | clk_ibuf/I
40.952 | 0.952 | tINS | RR | 15774 | IOB117[B] | clk_ibuf/O
42.186 | 1.234 | tNET | RR | 1 | R73C54[1][A] | u_rst_sync/sync_chain_1_s0/CLK
42.316 | 0.130 | tC2Q | RR | 12951 | R73C54[1][A] | u_rst_sync/sync_chain_1_s0/Q
43.191 | 0.875 | tNET | RR | 1 | R41C86[2][B] | u_hdmi/reset_pipe_1_s0/CLEAR

Data Required Path:

AT | DELAY | TYPE | RF | FANOUT | LOC | NODE
40.000 | 40.000 | | | | | active clock edge time
40.000 | 0.000 | | | | | pixel_clk
42.186 | 2.186 | tCL | RR | 154 | PLL_R[1] | u_hdmi/u_clk/u_pll/CLKOUT1
42.795 | 0.609 | tNET | RR | 1 | R41C86[2][B] | u_hdmi/reset_pipe_1_s0/CLK
42.830 | 0.035 | tUnc
42.783 | -0.048 | tHld | | 1 | R41C86[2][B] | u_hdmi/reset_pipe_1_s0

Path Statistics:

Clock Skew | 0.609
Hold Relationship | 0.000
Logic Level | 1
Arrival Clock Path Delay | cell: 0.952, 43.558%; route: 1.234, 56.442%
Arrival Data Path Delay | cell: 0.000, 0.000%; route: 0.875, 87.097%; tC2Q: 0.130, 12.903%
Required Clock Path Delay | cell: 0.000, 0.000%; route: 0.609, 100.000%

### Path6

Path Summary:

Slack | 0.408
Data Arrival Time | 43.191
Data Required Time | 42.783
From | u_rst_sync/sync_chain_1_s0
To | u_hdmi/reset_pipe_0_s0
Launch Clk | clk_sys:[R]
Latch Clk | pixel_clk:[R]

Data Arrival Path:

AT | DELAY | TYPE | RF | FANOUT | LOC | NODE
40.000 | 40.000 | | | | | active clock edge time
40.000 | 0.000 | | | | | clk_sys
40.000 | 0.000 | tCL | RR | 1 | IOB117[B] | clk_ibuf/I
40.952 | 0.952 | tINS | RR | 15774 | IOB117[B] | clk_ibuf/O
42.186 | 1.234 | tNET | RR | 1 | R73C54[1][A] | u_rst_sync/sync_chain_1_s0/CLK
42.316 | 0.130 | tC2Q | RR | 12951 | R73C54[1][A] | u_rst_sync/sync_chain_1_s0/Q
43.191 | 0.875 | tNET | RR | 1 | R41C86[2][A] | u_hdmi/reset_pipe_0_s0/CLEAR

Data Required Path:

AT | DELAY | TYPE | RF | FANOUT | LOC | NODE
40.000 | 40.000 | | | | | active clock edge time
40.000 | 0.000 | | | | | pixel_clk
42.186 | 2.186 | tCL | RR | 154 | PLL_R[1] | u_hdmi/u_clk/u_pll/CLKOUT1
42.795 | 0.609 | tNET | RR | 1 | R41C86[2][A] | u_hdmi/reset_pipe_0_s0/CLK
42.830 | 0.035 | tUnc
42.783 | -0.048 | tHld | | 1 | R41C86[2][A] | u_hdmi/reset_pipe_0_s0

Path Statistics:

Clock Skew | 0.609
Hold Relationship | 0.000
Logic Level | 1
Arrival Clock Path Delay | cell: 0.952, 43.558%; route: 1.234, 56.442%
Arrival Data Path Delay | cell: 0.000, 0.000%; route: 0.875, 87.097%; tC2Q: 0.130, 12.903%
Required Clock Path Delay | cell: 0.000, 0.000%; route: 0.609, 100.000%

### Path7

Path Summary:

Slack | 0.835
Data Arrival Time | 3.194
Data Required Time | 2.359
From | u_rst_sync/sync_chain_1_s0
To | u_hdmi/u_serializer/lanes[0].u_oser
Launch Clk | clk_sys:[R]
Latch Clk | serial_clk:[R]

Data Arrival Path:

AT | DELAY | TYPE | RF | FANOUT | LOC | NODE
0.000 | 0.000 | | | | | active clock edge time
0.000 | 0.000 | | | | | clk_sys
0.000 | 0.000 | tCL | RR | 1 | IOB117[B] | clk_ibuf/I
0.952 | 0.952 | tINS | RR | 15774 | IOB117[B] | clk_ibuf/O
2.186 | 1.234 | tNET | RR | 1 | R73C54[1][A] | u_rst_sync/sync_chain_1_s0/CLK
2.316 | 0.130 | tC2Q | RR | 12951 | R73C54[1][A] | u_rst_sync/sync_chain_1_s0/Q
3.194 | 0.878 | tNET | RR | 1 | IOR26[A] | u_hdmi/u_serializer/lanes[0].u_oser/RESET

Data Required Path:

AT | DELAY | TYPE | RF | FANOUT | LOC | NODE
0.000 | 0.000 | | | | | active clock edge time
0.000 | 0.000 | | | | | serial_clk
2.186 | 2.186 | tCL | RR | 4 | PLL_R[1] | u_hdmi/u_clk/u_pll/CLKOUT0
2.186 | 0.000 | tNET | RR | 1 | IOR26[A] | u_hdmi/u_serializer/lanes[0].u_oser/FCLK
2.221 | 0.035 | tUnc
2.359 | 0.138 | tHld | | 1 | IOR26[A] | u_hdmi/u_serializer/lanes[0].u_oser

Path Statistics:

Clock Skew | 0.000
Hold Relationship | 0.000
Logic Level | 1
Arrival Clock Path Delay | cell: 0.952, 43.558%; route: 1.234, 56.442%
Arrival Data Path Delay | cell: 0.000, 0.000%; route: 0.878, 87.143%; tC2Q: 0.130, 12.857%
Required Clock Path Delay | cell: 0.000, 0.000%; route: 0.000, 0.000%

### Path8

Path Summary:

Slack | 0.835
Data Arrival Time | 3.194
Data Required Time | 2.359
From | u_rst_sync/sync_chain_1_s0
To | u_hdmi/u_serializer/lanes[1].u_oser
Launch Clk | clk_sys:[R]
Latch Clk | serial_clk:[R]

Data Arrival Path:

AT | DELAY | TYPE | RF | FANOUT | LOC | NODE
0.000 | 0.000 | | | | | active clock edge time
0.000 | 0.000 | | | | | clk_sys
0.000 | 0.000 | tCL | RR | 1 | IOB117[B] | clk_ibuf/I
0.952 | 0.952 | tINS | RR | 15774 | IOB117[B] | clk_ibuf/O
2.186 | 1.234 | tNET | RR | 1 | R73C54[1][A] | u_rst_sync/sync_chain_1_s0/CLK
2.316 | 0.130 | tC2Q | RR | 12951 | R73C54[1][A] | u_rst_sync/sync_chain_1_s0/Q
3.194 | 0.878 | tNET | RR | 1 | IOR22[A] | u_hdmi/u_serializer/lanes[1].u_oser/RESET

Data Required Path:

AT | DELAY | TYPE | RF | FANOUT | LOC | NODE
0.000 | 0.000 | | | | | active clock edge time
0.000 | 0.000 | | | | | serial_clk
2.186 | 2.186 | tCL | RR | 4 | PLL_R[1] | u_hdmi/u_clk/u_pll/CLKOUT0
2.186 | 0.000 | tNET | RR | 1 | IOR22[A] | u_hdmi/u_serializer/lanes[1].u_oser/FCLK
2.221 | 0.035 | tUnc
2.359 | 0.138 | tHld | | 1 | IOR22[A] | u_hdmi/u_serializer/lanes[1].u_oser

Path Statistics:

Clock Skew | 0.000
Hold Relationship | 0.000
Logic Level | 1
Arrival Clock Path Delay | cell: 0.952, 43.558%; route: 1.234, 56.442%
Arrival Data Path Delay | cell: 0.000, 0.000%; route: 0.878, 87.143%; tC2Q: 0.130, 12.857%
Required Clock Path Delay | cell: 0.000, 0.000%; route: 0.000, 0.000%

### Path9

Path Summary:

Slack | 0.835
Data Arrival Time | 3.194
Data Required Time | 2.359
From | u_rst_sync/sync_chain_1_s0
To | u_hdmi/u_serializer/lanes[2].u_oser
Launch Clk | clk_sys:[R]
Latch Clk | serial_clk:[R]

Data Arrival Path:

AT | DELAY | TYPE | RF | FANOUT | LOC | NODE
0.000 | 0.000 | | | | | active clock edge time
0.000 | 0.000 | | | | | clk_sys
0.000 | 0.000 | tCL | RR | 1 | IOB117[B] | clk_ibuf/I
0.952 | 0.952 | tINS | RR | 15774 | IOB117[B] | clk_ibuf/O
2.186 | 1.234 | tNET | RR | 1 | R73C54[1][A] | u_rst_sync/sync_chain_1_s0/CLK
2.316 | 0.130 | tC2Q | RR | 12951 | R73C54[1][A] | u_rst_sync/sync_chain_1_s0/Q
3.194 | 0.878 | tNET | RR | 1 | IOR39[A] | u_hdmi/u_serializer/lanes[2].u_oser/RESET

Data Required Path:

AT | DELAY | TYPE | RF | FANOUT | LOC | NODE
0.000 | 0.000 | | | | | active clock edge time
0.000 | 0.000 | | | | | serial_clk
2.186 | 2.186 | tCL | RR | 4 | PLL_R[1] | u_hdmi/u_clk/u_pll/CLKOUT0
2.186 | 0.000 | tNET | RR | 1 | IOR39[A] | u_hdmi/u_serializer/lanes[2].u_oser/FCLK
2.221 | 0.035 | tUnc
2.359 | 0.138 | tHld | | 1 | IOR39[A] | u_hdmi/u_serializer/lanes[2].u_oser

Path Statistics:

Clock Skew | 0.000
Hold Relationship | 0.000
Logic Level | 1
Arrival Clock Path Delay | cell: 0.952, 43.558%; route: 1.234, 56.442%
Arrival Data Path Delay | cell: 0.000, 0.000%; route: 0.878, 87.143%; tC2Q: 0.130, 12.857%
Required Clock Path Delay | cell: 0.000, 0.000%; route: 0.000, 0.000%

### Path10

Path Summary:

Slack | 0.835
Data Arrival Time | 3.194
Data Required Time | 2.359
From | u_rst_sync/sync_chain_1_s0
To | u_hdmi/u_serializer/lanes[3].u_oser
Launch Clk | clk_sys:[R]
Latch Clk | serial_clk:[R]

Data Arrival Path:

AT | DELAY | TYPE | RF | FANOUT | LOC | NODE
0.000 | 0.000 | | | | | active clock edge time
0.000 | 0.000 | | | | | clk_sys
0.000 | 0.000 | tCL | RR | 1 | IOB117[B] | clk_ibuf/I
0.952 | 0.952 | tINS | RR | 15774 | IOB117[B] | clk_ibuf/O
2.186 | 1.234 | tNET | RR | 1 | R73C54[1][A] | u_rst_sync/sync_chain_1_s0/CLK
2.316 | 0.130 | tC2Q | RR | 12951 | R73C54[1][A] | u_rst_sync/sync_chain_1_s0/Q
3.194 | 0.878 | tNET | RR | 1 | IOR24[A] | u_hdmi/u_serializer/lanes[3].u_oser/RESET

Data Required Path:

AT | DELAY | TYPE | RF | FANOUT | LOC | NODE
0.000 | 0.000 | | | | | active clock edge time
0.000 | 0.000 | | | | | serial_clk
2.186 | 2.186 | tCL | RR | 4 | PLL_R[1] | u_hdmi/u_clk/u_pll/CLKOUT0
2.186 | 0.000 | tNET | RR | 1 | IOR24[A] | u_hdmi/u_serializer/lanes[3].u_oser/FCLK
2.221 | 0.035 | tUnc
2.359 | 0.138 | tHld | | 1 | IOR24[A] | u_hdmi/u_serializer/lanes[3].u_oser

Path Statistics:

Clock Skew | 0.000
Hold Relationship | 0.000
Logic Level | 1
Arrival Clock Path Delay | cell: 0.952, 43.558%; route: 1.234, 56.442%
Arrival Data Path Delay | cell: 0.000, 0.000%; route: 0.878, 87.143%; tC2Q: 0.130, 12.857%
Required Clock Path Delay | cell: 0.000, 0.000%; route: 0.000, 0.000%

### Path11

Path Summary:

Slack | 0.837
Data Arrival Time | 23.194
Data Required Time | 22.357
From | u_rst_sync/sync_chain_1_s0
To | u_hdmi/u_serializer/lanes[0].u_oser
Launch Clk | clk_sys:[R]
Latch Clk | serial_clk:[F]

Data Arrival Path:

AT | DELAY | TYPE | RF | FANOUT | LOC | NODE
20.000 | 20.000 | | | | | active clock edge time
20.000 | 0.000 | | | | | clk_sys
20.000 | 0.000 | tCL | RR | 1 | IOB117[B] | clk_ibuf/I
20.952 | 0.952 | tINS | RR | 15774 | IOB117[B] | clk_ibuf/O
22.186 | 1.234 | tNET | RR | 1 | R73C54[1][A] | u_rst_sync/sync_chain_1_s0/CLK
22.316 | 0.130 | tC2Q | RR | 12951 | R73C54[1][A] | u_rst_sync/sync_chain_1_s0/Q
23.194 | 0.878 | tNET | RR | 1 | IOR26[A] | u_hdmi/u_serializer/lanes[0].u_oser/RESET

Data Required Path:

AT | DELAY | TYPE | RF | FANOUT | LOC | NODE
20.000 | 20.000 | | | | | active clock edge time
20.000 | 0.000 | | | | | serial_clk
22.186 | 2.186 | tCL | FF | 4 | PLL_R[1] | u_hdmi/u_clk/u_pll/CLKOUT0
22.186 | 0.000 | tNET | FF | 1 | IOR26[A] | u_hdmi/u_serializer/lanes[0].u_oser/FCLK
22.221 | 0.035 | tUnc
22.357 | 0.136 | tHld | | 1 | IOR26[A] | u_hdmi/u_serializer/lanes[0].u_oser

Path Statistics:

Clock Skew | 0.000
Hold Relationship | 0.000
Logic Level | 1
Arrival Clock Path Delay | cell: 0.952, 43.558%; route: 1.234, 56.442%
Arrival Data Path Delay | cell: 0.000, 0.000%; route: 0.878, 87.143%; tC2Q: 0.130, 12.857%
Required Clock Path Delay | cell: 0.000, 0.000%; route: 0.000, 0.000%

### Path12

Path Summary:

Slack | 0.837
Data Arrival Time | 23.194
Data Required Time | 22.357
From | u_rst_sync/sync_chain_1_s0
To | u_hdmi/u_serializer/lanes[1].u_oser
Launch Clk | clk_sys:[R]
Latch Clk | serial_clk:[F]

Data Arrival Path:

AT | DELAY | TYPE | RF | FANOUT | LOC | NODE
20.000 | 20.000 | | | | | active clock edge time
20.000 | 0.000 | | | | | clk_sys
20.000 | 0.000 | tCL | RR | 1 | IOB117[B] | clk_ibuf/I
20.952 | 0.952 | tINS | RR | 15774 | IOB117[B] | clk_ibuf/O
22.186 | 1.234 | tNET | RR | 1 | R73C54[1][A] | u_rst_sync/sync_chain_1_s0/CLK
22.316 | 0.130 | tC2Q | RR | 12951 | R73C54[1][A] | u_rst_sync/sync_chain_1_s0/Q
23.194 | 0.878 | tNET | RR | 1 | IOR22[A] | u_hdmi/u_serializer/lanes[1].u_oser/RESET

Data Required Path:

AT | DELAY | TYPE | RF | FANOUT | LOC | NODE
20.000 | 20.000 | | | | | active clock edge time
20.000 | 0.000 | | | | | serial_clk
22.186 | 2.186 | tCL | FF | 4 | PLL_R[1] | u_hdmi/u_clk/u_pll/CLKOUT0
22.186 | 0.000 | tNET | FF | 1 | IOR22[A] | u_hdmi/u_serializer/lanes[1].u_oser/FCLK
22.221 | 0.035 | tUnc
22.357 | 0.136 | tHld | | 1 | IOR22[A] | u_hdmi/u_serializer/lanes[1].u_oser

Path Statistics:

Clock Skew | 0.000
Hold Relationship | 0.000
Logic Level | 1
Arrival Clock Path Delay | cell: 0.952, 43.558%; route: 1.234, 56.442%
Arrival Data Path Delay | cell: 0.000, 0.000%; route: 0.878, 87.143%; tC2Q: 0.130, 12.857%
Required Clock Path Delay | cell: 0.000, 0.000%; route: 0.000, 0.000%

### Path13

Path Summary:

Slack | 0.837
Data Arrival Time | 23.194
Data Required Time | 22.357
From | u_rst_sync/sync_chain_1_s0
To | u_hdmi/u_serializer/lanes[2].u_oser
Launch Clk | clk_sys:[R]
Latch Clk | serial_clk:[F]

Data Arrival Path:

AT | DELAY | TYPE | RF | FANOUT | LOC | NODE
20.000 | 20.000 | | | | | active clock edge time
20.000 | 0.000 | | | | | clk_sys
20.000 | 0.000 | tCL | RR | 1 | IOB117[B] | clk_ibuf/I
20.952 | 0.952 | tINS | RR | 15774 | IOB117[B] | clk_ibuf/O
22.186 | 1.234 | tNET | RR | 1 | R73C54[1][A] | u_rst_sync/sync_chain_1_s0/CLK
22.316 | 0.130 | tC2Q | RR | 12951 | R73C54[1][A] | u_rst_sync/sync_chain_1_s0/Q
23.194 | 0.878 | tNET | RR | 1 | IOR39[A] | u_hdmi/u_serializer/lanes[2].u_oser/RESET

Data Required Path:

AT | DELAY | TYPE | RF | FANOUT | LOC | NODE
20.000 | 20.000 | | | | | active clock edge time
20.000 | 0.000 | | | | | serial_clk
22.186 | 2.186 | tCL | FF | 4 | PLL_R[1] | u_hdmi/u_clk/u_pll/CLKOUT0
22.186 | 0.000 | tNET | FF | 1 | IOR39[A] | u_hdmi/u_serializer/lanes[2].u_oser/FCLK
22.221 | 0.035 | tUnc
22.357 | 0.136 | tHld | | 1 | IOR39[A] | u_hdmi/u_serializer/lanes[2].u_oser

Path Statistics:

Clock Skew | 0.000
Hold Relationship | 0.000
Logic Level | 1
Arrival Clock Path Delay | cell: 0.952, 43.558%; route: 1.234, 56.442%
Arrival Data Path Delay | cell: 0.000, 0.000%; route: 0.878, 87.143%; tC2Q: 0.130, 12.857%
Required Clock Path Delay | cell: 0.000, 0.000%; route: 0.000, 0.000%

### Path14

Path Summary:

Slack | 0.837
Data Arrival Time | 23.194
Data Required Time | 22.357
From | u_rst_sync/sync_chain_1_s0
To | u_hdmi/u_serializer/lanes[3].u_oser
Launch Clk | clk_sys:[R]
Latch Clk | serial_clk:[F]

Data Arrival Path:

AT | DELAY | TYPE | RF | FANOUT | LOC | NODE
20.000 | 20.000 | | | | | active clock edge time
20.000 | 0.000 | | | | | clk_sys
20.000 | 0.000 | tCL | RR | 1 | IOB117[B] | clk_ibuf/I
20.952 | 0.952 | tINS | RR | 15774 | IOB117[B] | clk_ibuf/O
22.186 | 1.234 | tNET | RR | 1 | R73C54[1][A] | u_rst_sync/sync_chain_1_s0/CLK
22.316 | 0.130 | tC2Q | RR | 12951 | R73C54[1][A] | u_rst_sync/sync_chain_1_s0/Q
23.194 | 0.878 | tNET | RR | 1 | IOR24[A] | u_hdmi/u_serializer/lanes[3].u_oser/RESET

Data Required Path:

AT | DELAY | TYPE | RF | FANOUT | LOC | NODE
20.000 | 20.000 | | | | | active clock edge time
20.000 | 0.000 | | | | | serial_clk
22.186 | 2.186 | tCL | FF | 4 | PLL_R[1] | u_hdmi/u_clk/u_pll/CLKOUT0
22.186 | 0.000 | tNET | FF | 1 | IOR24[A] | u_hdmi/u_serializer/lanes[3].u_oser/FCLK
22.221 | 0.035 | tUnc
22.357 | 0.136 | tHld | | 1 | IOR24[A] | u_hdmi/u_serializer/lanes[3].u_oser

Path Statistics:

Clock Skew | 0.000
Hold Relationship | 0.000
Logic Level | 1
Arrival Clock Path Delay | cell: 0.952, 43.558%; route: 1.234, 56.442%
Arrival Data Path Delay | cell: 0.000, 0.000%; route: 0.878, 87.143%; tC2Q: 0.130, 12.857%
Required Clock Path Delay | cell: 0.000, 0.000%; route: 0.000, 0.000%

### Path15

Path Summary:

Slack | 0.868
Data Arrival Time | 3.191
Data Required Time | 2.323
From | u_rst_sync/sync_chain_1_s0
To | g_sound.u_looper/last_inc_r[3]_4_s0
Launch Clk | clk_sys:[R]
Latch Clk | clk_sys:[R]

Data Arrival Path:

AT | DELAY | TYPE | RF | FANOUT | LOC | NODE
0.000 | 0.000 | | | | | active clock edge time
0.000 | 0.000 | | | | | clk_sys
0.000 | 0.000 | tCL | RR | 1 | IOB117[B] | clk_ibuf/I
0.952 | 0.952 | tINS | RR | 15774 | IOB117[B] | clk_ibuf/O
2.186 | 1.234 | tNET | RR | 1 | R73C54[1][A] | u_rst_sync/sync_chain_1_s0/CLK
2.316 | 0.130 | tC2Q | RR | 12951 | R73C54[1][A] | u_rst_sync/sync_chain_1_s0/Q
3.191 | 0.876 | tNET | RR | 1 | R37C20[1][A] | g_sound.u_looper/last_inc_r[3]_4_s0/CLEAR

Data Required Path:

AT | DELAY | TYPE | RF | FANOUT | LOC | NODE
0.000 | 0.000 | | | | | active clock edge time
0.000 | 0.000 | | | | | clk_sys
0.000 | 0.000 | tCL | RR | 1 | IOB117[B] | clk_ibuf/I
0.952 | 0.952 | tINS | RR | 15774 | IOB117[B] | clk_ibuf/O
2.371 | 1.418 | tNET | RR | 1 | R37C20[1][A] | g_sound.u_looper/last_inc_r[3]_4_s0/CLK
2.323 | -0.048 | tHld | | 1 | R37C20[1][A] | g_sound.u_looper/last_inc_r[3]_4_s0

Path Statistics:

Clock Skew | 0.185
Hold Relationship | 0.000
Logic Level | 1
Arrival Clock Path Delay | cell: 0.952, 43.558%; route: 1.234, 56.442%
Arrival Data Path Delay | cell: 0.000, 0.000%; route: 0.876, 87.108%; tC2Q: 0.130, 12.892%
Required Clock Path Delay | cell: 0.952, 40.168%; route: 1.418, 59.832%

### Path16

Path Summary:

Slack | 0.868
Data Arrival Time | 3.191
Data Required Time | 2.323
From | u_rst_sync/sync_chain_1_s0
To | g_sound.u_looper/last_inc_r[3]_23_s0
Launch Clk | clk_sys:[R]
Latch Clk | clk_sys:[R]

Data Arrival Path:

AT | DELAY | TYPE | RF | FANOUT | LOC | NODE
0.000 | 0.000 | | | | | active clock edge time
0.000 | 0.000 | | | | | clk_sys
0.000 | 0.000 | tCL | RR | 1 | IOB117[B] | clk_ibuf/I
0.952 | 0.952 | tINS | RR | 15774 | IOB117[B] | clk_ibuf/O
2.186 | 1.234 | tNET | RR | 1 | R73C54[1][A] | u_rst_sync/sync_chain_1_s0/CLK
2.316 | 0.130 | tC2Q | RR | 12951 | R73C54[1][A] | u_rst_sync/sync_chain_1_s0/Q
3.191 | 0.876 | tNET | RR | 1 | R37C16[3][A] | g_sound.u_looper/last_inc_r[3]_23_s0/CLEAR

Data Required Path:

AT | DELAY | TYPE | RF | FANOUT | LOC | NODE
0.000 | 0.000 | | | | | active clock edge time
0.000 | 0.000 | | | | | clk_sys
0.000 | 0.000 | tCL | RR | 1 | IOB117[B] | clk_ibuf/I
0.952 | 0.952 | tINS | RR | 15774 | IOB117[B] | clk_ibuf/O
2.371 | 1.418 | tNET | RR | 1 | R37C16[3][A] | g_sound.u_looper/last_inc_r[3]_23_s0/CLK
2.323 | -0.048 | tHld | | 1 | R37C16[3][A] | g_sound.u_looper/last_inc_r[3]_23_s0

Path Statistics:

Clock Skew | 0.185
Hold Relationship | 0.000
Logic Level | 1
Arrival Clock Path Delay | cell: 0.952, 43.558%; route: 1.234, 56.442%
Arrival Data Path Delay | cell: 0.000, 0.000%; route: 0.876, 87.108%; tC2Q: 0.130, 12.892%
Required Clock Path Delay | cell: 0.952, 40.168%; route: 1.418, 59.832%

### Path17

Path Summary:

Slack | 0.876
Data Arrival Time | 3.195
Data Required Time | 2.319
From | u_rst_sync/sync_chain_1_s0
To | g_sound.u_looper/last_inc_r[11]_4_s0
Launch Clk | clk_sys:[R]
Latch Clk | clk_sys:[R]

Data Arrival Path:

AT | DELAY | TYPE | RF | FANOUT | LOC | NODE
0.000 | 0.000 | | | | | active clock edge time
0.000 | 0.000 | | | | | clk_sys
0.000 | 0.000 | tCL | RR | 1 | IOB117[B] | clk_ibuf/I
0.952 | 0.952 | tINS | RR | 15774 | IOB117[B] | clk_ibuf/O
2.186 | 1.234 | tNET | RR | 1 | R73C54[1][A] | u_rst_sync/sync_chain_1_s0/CLK
2.316 | 0.130 | tC2Q | RR | 12951 | R73C54[1][A] | u_rst_sync/sync_chain_1_s0/Q
3.195 | 0.879 | tNET | RR | 1 | R37C19[0][B] | g_sound.u_looper/last_inc_r[11]_4_s0/CLEAR

Data Required Path:

AT | DELAY | TYPE | RF | FANOUT | LOC | NODE
0.000 | 0.000 | | | | | active clock edge time
0.000 | 0.000 | | | | | clk_sys
0.000 | 0.000 | tCL | RR | 1 | IOB117[B] | clk_ibuf/I
0.952 | 0.952 | tINS | RR | 15774 | IOB117[B] | clk_ibuf/O
2.367 | 1.415 | tNET | RR | 1 | R37C19[0][B] | g_sound.u_looper/last_inc_r[11]_4_s0/CLK
2.319 | -0.048 | tHld | | 1 | R37C19[0][B] | g_sound.u_looper/last_inc_r[11]_4_s0

Path Statistics:

Clock Skew | 0.181
Hold Relationship | 0.000
Logic Level | 1
Arrival Clock Path Delay | cell: 0.952, 43.558%; route: 1.234, 56.442%
Arrival Data Path Delay | cell: 0.000, 0.000%; route: 0.879, 87.154%; tC2Q: 0.130, 12.846%
Required Clock Path Delay | cell: 0.952, 40.230%; route: 1.415, 59.770%

### Path18

Path Summary:

Slack | 0.876
Data Arrival Time | 3.195
Data Required Time | 2.319
From | u_rst_sync/sync_chain_1_s0
To | g_sound.u_looper/last_inc_r[11]_23_s0
Launch Clk | clk_sys:[R]
Latch Clk | clk_sys:[R]

Data Arrival Path:

AT | DELAY | TYPE | RF | FANOUT | LOC | NODE
0.000 | 0.000 | | | | | active clock edge time
0.000 | 0.000 | | | | | clk_sys
0.000 | 0.000 | tCL | RR | 1 | IOB117[B] | clk_ibuf/I
0.952 | 0.952 | tINS | RR | 15774 | IOB117[B] | clk_ibuf/O
2.186 | 1.234 | tNET | RR | 1 | R73C54[1][A] | u_rst_sync/sync_chain_1_s0/CLK
2.316 | 0.130 | tC2Q | RR | 12951 | R73C54[1][A] | u_rst_sync/sync_chain_1_s0/Q
3.195 | 0.879 | tNET | RR | 1 | R37C19[0][A] | g_sound.u_looper/last_inc_r[11]_23_s0/CLEAR

Data Required Path:

AT | DELAY | TYPE | RF | FANOUT | LOC | NODE
0.000 | 0.000 | | | | | active clock edge time
0.000 | 0.000 | | | | | clk_sys
0.000 | 0.000 | tCL | RR | 1 | IOB117[B] | clk_ibuf/I
0.952 | 0.952 | tINS | RR | 15774 | IOB117[B] | clk_ibuf/O
2.367 | 1.415 | tNET | RR | 1 | R37C19[0][A] | g_sound.u_looper/last_inc_r[11]_23_s0/CLK
2.319 | -0.048 | tHld | | 1 | R37C19[0][A] | g_sound.u_looper/last_inc_r[11]_23_s0

Path Statistics:

Clock Skew | 0.181
Hold Relationship | 0.000
Logic Level | 1
Arrival Clock Path Delay | cell: 0.952, 43.558%; route: 1.234, 56.442%
Arrival Data Path Delay | cell: 0.000, 0.000%; route: 0.879, 87.154%; tC2Q: 0.130, 12.846%
Required Clock Path Delay | cell: 0.952, 40.230%; route: 1.415, 59.770%

### Path19

Path Summary:

Slack | 0.885
Data Arrival Time | 3.204
Data Required Time | 2.319
From | u_rst_sync/sync_chain_1_s0
To | g_sound.u_looper/play_valid_o_s0
Launch Clk | clk_sys:[R]
Latch Clk | clk_sys:[R]

Data Arrival Path:

AT | DELAY | TYPE | RF | FANOUT | LOC | NODE
0.000 | 0.000 | | | | | active clock edge time
0.000 | 0.000 | | | | | clk_sys
0.000 | 0.000 | tCL | RR | 1 | IOB117[B] | clk_ibuf/I
0.952 | 0.952 | tINS | RR | 15774 | IOB117[B] | clk_ibuf/O
2.186 | 1.234 | tNET | RR | 1 | R73C54[1][A] | u_rst_sync/sync_chain_1_s0/CLK
2.316 | 0.130 | tC2Q | RR | 12951 | R73C54[1][A] | u_rst_sync/sync_chain_1_s0/Q
3.204 | 0.888 | tNET | RR | 1 | R35C5[2][A] | g_sound.u_looper/play_valid_o_s0/CLEAR

Data Required Path:

AT | DELAY | TYPE | RF | FANOUT | LOC | NODE
0.000 | 0.000 | | | | | active clock edge time
0.000 | 0.000 | | | | | clk_sys
0.000 | 0.000 | tCL | RR | 1 | IOB117[B] | clk_ibuf/I
0.952 | 0.952 | tINS | RR | 15774 | IOB117[B] | clk_ibuf/O
2.367 | 1.415 | tNET | RR | 1 | R35C5[2][A] | g_sound.u_looper/play_valid_o_s0/CLK
2.319 | -0.048 | tHld | | 1 | R35C5[2][A] | g_sound.u_looper/play_valid_o_s0

Path Statistics:

Clock Skew | 0.181
Hold Relationship | 0.000
Logic Level | 1
Arrival Clock Path Delay | cell: 0.952, 43.558%; route: 1.234, 56.442%
Arrival Data Path Delay | cell: 0.000, 0.000%; route: 0.888, 87.268%; tC2Q: 0.130, 12.732%
Required Clock Path Delay | cell: 0.952, 40.230%; route: 1.415, 59.770%

### Path20

Path Summary:

Slack | 0.888
Data Arrival Time | 3.211
Data Required Time | 2.323
From | u_rst_sync/sync_chain_1_s0
To | g_sound.u_calib1/quo_r_15_s1
Launch Clk | clk_sys:[R]
Latch Clk | clk_sys:[R]

Data Arrival Path:

AT | DELAY | TYPE | RF | FANOUT | LOC | NODE
0.000 | 0.000 | | | | | active clock edge time
0.000 | 0.000 | | | | | clk_sys
0.000 | 0.000 | tCL | RR | 1 | IOB117[B] | clk_ibuf/I
0.952 | 0.952 | tINS | RR | 15774 | IOB117[B] | clk_ibuf/O
2.186 | 1.234 | tNET | RR | 1 | R73C54[1][A] | u_rst_sync/sync_chain_1_s0/CLK
2.316 | 0.130 | tC2Q | RR | 12951 | R73C54[1][A] | u_rst_sync/sync_chain_1_s0/Q
3.211 | 0.895 | tNET | RR | 1 | R30C36[3][A] | g_sound.u_calib1/quo_r_15_s1/CLEAR

Data Required Path:

AT | DELAY | TYPE | RF | FANOUT | LOC | NODE
0.000 | 0.000 | | | | | active clock edge time
0.000 | 0.000 | | | | | clk_sys
0.000 | 0.000 | tCL | RR | 1 | IOB117[B] | clk_ibuf/I
0.952 | 0.952 | tINS | RR | 15774 | IOB117[B] | clk_ibuf/O
2.371 | 1.418 | tNET | RR | 1 | R30C36[3][A] | g_sound.u_calib1/quo_r_15_s1/CLK
2.323 | -0.048 | tHld | | 1 | R30C36[3][A] | g_sound.u_calib1/quo_r_15_s1

Path Statistics:

Clock Skew | 0.185
Hold Relationship | 0.000
Logic Level | 1
Arrival Clock Path Delay | cell: 0.952, 43.558%; route: 1.234, 56.442%
Arrival Data Path Delay | cell: 0.000, 0.000%; route: 0.895, 87.357%; tC2Q: 0.130, 12.643%
Required Clock Path Delay | cell: 0.952, 40.168%; route: 1.418, 59.832%

### Path21

Path Summary:

Slack | 0.888
Data Arrival Time | 3.211
Data Required Time | 2.323
From | u_rst_sync/sync_chain_1_s0
To | g_sound.u_calib1/rem_r_3_s1
Launch Clk | clk_sys:[R]
Latch Clk | clk_sys:[R]

Data Arrival Path:

AT | DELAY | TYPE | RF | FANOUT | LOC | NODE
0.000 | 0.000 | | | | | active clock edge time
0.000 | 0.000 | | | | | clk_sys
0.000 | 0.000 | tCL | RR | 1 | IOB117[B] | clk_ibuf/I
0.952 | 0.952 | tINS | RR | 15774 | IOB117[B] | clk_ibuf/O
2.186 | 1.234 | tNET | RR | 1 | R73C54[1][A] | u_rst_sync/sync_chain_1_s0/CLK
2.316 | 0.130 | tC2Q | RR | 12951 | R73C54[1][A] | u_rst_sync/sync_chain_1_s0/Q
3.211 | 0.895 | tNET | RR | 1 | R30C8[3][A] | g_sound.u_calib1/rem_r_3_s1/CLEAR

Data Required Path:

AT | DELAY | TYPE | RF | FANOUT | LOC | NODE
0.000 | 0.000 | | | | | active clock edge time
0.000 | 0.000 | | | | | clk_sys
0.000 | 0.000 | tCL | RR | 1 | IOB117[B] | clk_ibuf/I
0.952 | 0.952 | tINS | RR | 15774 | IOB117[B] | clk_ibuf/O
2.371 | 1.418 | tNET | RR | 1 | R30C8[3][A] | g_sound.u_calib1/rem_r_3_s1/CLK
2.323 | -0.048 | tHld | | 1 | R30C8[3][A] | g_sound.u_calib1/rem_r_3_s1

Path Statistics:

Clock Skew | 0.185
Hold Relationship | 0.000
Logic Level | 1
Arrival Clock Path Delay | cell: 0.952, 43.558%; route: 1.234, 56.442%
Arrival Data Path Delay | cell: 0.000, 0.000%; route: 0.895, 87.357%; tC2Q: 0.130, 12.643%
Required Clock Path Delay | cell: 0.952, 40.168%; route: 1.418, 59.832%

### Path22

Path Summary:

Slack | 0.888
Data Arrival Time | 3.211
Data Required Time | 2.323
From | u_rst_sync/sync_chain_1_s0
To | g_sound.u_calib1/rem_r_4_s1
Launch Clk | clk_sys:[R]
Latch Clk | clk_sys:[R]

Data Arrival Path:

AT | DELAY | TYPE | RF | FANOUT | LOC | NODE
0.000 | 0.000 | | | | | active clock edge time
0.000 | 0.000 | | | | | clk_sys
0.000 | 0.000 | tCL | RR | 1 | IOB117[B] | clk_ibuf/I
0.952 | 0.952 | tINS | RR | 15774 | IOB117[B] | clk_ibuf/O
2.186 | 1.234 | tNET | RR | 1 | R73C54[1][A] | u_rst_sync/sync_chain_1_s0/CLK
2.316 | 0.130 | tC2Q | RR | 12951 | R73C54[1][A] | u_rst_sync/sync_chain_1_s0/Q
3.211 | 0.895 | tNET | RR | 1 | R30C8[2][B] | g_sound.u_calib1/rem_r_4_s1/CLEAR

Data Required Path:

AT | DELAY | TYPE | RF | FANOUT | LOC | NODE
0.000 | 0.000 | | | | | active clock edge time
0.000 | 0.000 | | | | | clk_sys
0.000 | 0.000 | tCL | RR | 1 | IOB117[B] | clk_ibuf/I
0.952 | 0.952 | tINS | RR | 15774 | IOB117[B] | clk_ibuf/O
2.371 | 1.418 | tNET | RR | 1 | R30C8[2][B] | g_sound.u_calib1/rem_r_4_s1/CLK
2.323 | -0.048 | tHld | | 1 | R30C8[2][B] | g_sound.u_calib1/rem_r_4_s1

Path Statistics:

Clock Skew | 0.185
Hold Relationship | 0.000
Logic Level | 1
Arrival Clock Path Delay | cell: 0.952, 43.558%; route: 1.234, 56.442%
Arrival Data Path Delay | cell: 0.000, 0.000%; route: 0.895, 87.357%; tC2Q: 0.130, 12.643%
Required Clock Path Delay | cell: 0.952, 40.168%; route: 1.418, 59.832%

### Path23

Path Summary:

Slack | 0.888
Data Arrival Time | 3.211
Data Required Time | 2.323
From | u_rst_sync/sync_chain_1_s0
To | g_sound.u_calib1/rem_r_5_s1
Launch Clk | clk_sys:[R]
Latch Clk | clk_sys:[R]

Data Arrival Path:

AT | DELAY | TYPE | RF | FANOUT | LOC | NODE
0.000 | 0.000 | | | | | active clock edge time
0.000 | 0.000 | | | | | clk_sys
0.000 | 0.000 | tCL | RR | 1 | IOB117[B] | clk_ibuf/I
0.952 | 0.952 | tINS | RR | 15774 | IOB117[B] | clk_ibuf/O
2.186 | 1.234 | tNET | RR | 1 | R73C54[1][A] | u_rst_sync/sync_chain_1_s0/CLK
2.316 | 0.130 | tC2Q | RR | 12951 | R73C54[1][A] | u_rst_sync/sync_chain_1_s0/Q
3.211 | 0.895 | tNET | RR | 1 | R30C8[2][A] | g_sound.u_calib1/rem_r_5_s1/CLEAR

Data Required Path:

AT | DELAY | TYPE | RF | FANOUT | LOC | NODE
0.000 | 0.000 | | | | | active clock edge time
0.000 | 0.000 | | | | | clk_sys
0.000 | 0.000 | tCL | RR | 1 | IOB117[B] | clk_ibuf/I
0.952 | 0.952 | tINS | RR | 15774 | IOB117[B] | clk_ibuf/O
2.371 | 1.418 | tNET | RR | 1 | R30C8[2][A] | g_sound.u_calib1/rem_r_5_s1/CLK
2.323 | -0.048 | tHld | | 1 | R30C8[2][A] | g_sound.u_calib1/rem_r_5_s1

Path Statistics:

Clock Skew | 0.185
Hold Relationship | 0.000
Logic Level | 1
Arrival Clock Path Delay | cell: 0.952, 43.558%; route: 1.234, 56.442%
Arrival Data Path Delay | cell: 0.000, 0.000%; route: 0.895, 87.357%; tC2Q: 0.130, 12.643%
Required Clock Path Delay | cell: 0.952, 40.168%; route: 1.418, 59.832%

### Path24

Path Summary:

Slack | 0.888
Data Arrival Time | 3.211
Data Required Time | 2.323
From | u_rst_sync/sync_chain_1_s0
To | g_sound.u_calib1/rem_r_6_s1
Launch Clk | clk_sys:[R]
Latch Clk | clk_sys:[R]

Data Arrival Path:

AT | DELAY | TYPE | RF | FANOUT | LOC | NODE
0.000 | 0.000 | | | | | active clock edge time
0.000 | 0.000 | | | | | clk_sys
0.000 | 0.000 | tCL | RR | 1 | IOB117[B] | clk_ibuf/I
0.952 | 0.952 | tINS | RR | 15774 | IOB117[B] | clk_ibuf/O
2.186 | 1.234 | tNET | RR | 1 | R73C54[1][A] | u_rst_sync/sync_chain_1_s0/CLK
2.316 | 0.130 | tC2Q | RR | 12951 | R73C54[1][A] | u_rst_sync/sync_chain_1_s0/Q
3.211 | 0.895 | tNET | RR | 1 | R30C8[1][B] | g_sound.u_calib1/rem_r_6_s1/CLEAR

Data Required Path:

AT | DELAY | TYPE | RF | FANOUT | LOC | NODE
0.000 | 0.000 | | | | | active clock edge time
0.000 | 0.000 | | | | | clk_sys
0.000 | 0.000 | tCL | RR | 1 | IOB117[B] | clk_ibuf/I
0.952 | 0.952 | tINS | RR | 15774 | IOB117[B] | clk_ibuf/O
2.371 | 1.418 | tNET | RR | 1 | R30C8[1][B] | g_sound.u_calib1/rem_r_6_s1/CLK
2.323 | -0.048 | tHld | | 1 | R30C8[1][B] | g_sound.u_calib1/rem_r_6_s1

Path Statistics:

Clock Skew | 0.185
Hold Relationship | 0.000
Logic Level | 1
Arrival Clock Path Delay | cell: 0.952, 43.558%; route: 1.234, 56.442%
Arrival Data Path Delay | cell: 0.000, 0.000%; route: 0.895, 87.357%; tC2Q: 0.130, 12.643%
Required Clock Path Delay | cell: 0.952, 40.168%; route: 1.418, 59.832%

### Path25

Path Summary:

Slack | 0.888
Data Arrival Time | 3.211
Data Required Time | 2.323
From | u_rst_sync/sync_chain_1_s0
To | g_sound.u_calib1/rem_r_7_s1
Launch Clk | clk_sys:[R]
Latch Clk | clk_sys:[R]

Data Arrival Path:

AT | DELAY | TYPE | RF | FANOUT | LOC | NODE
0.000 | 0.000 | | | | | active clock edge time
0.000 | 0.000 | | | | | clk_sys
0.000 | 0.000 | tCL | RR | 1 | IOB117[B] | clk_ibuf/I
0.952 | 0.952 | tINS | RR | 15774 | IOB117[B] | clk_ibuf/O
2.186 | 1.234 | tNET | RR | 1 | R73C54[1][A] | u_rst_sync/sync_chain_1_s0/CLK
2.316 | 0.130 | tC2Q | RR | 12951 | R73C54[1][A] | u_rst_sync/sync_chain_1_s0/Q
3.211 | 0.895 | tNET | RR | 1 | R30C8[1][A] | g_sound.u_calib1/rem_r_7_s1/CLEAR

Data Required Path:

AT | DELAY | TYPE | RF | FANOUT | LOC | NODE
0.000 | 0.000 | | | | | active clock edge time
0.000 | 0.000 | | | | | clk_sys
0.000 | 0.000 | tCL | RR | 1 | IOB117[B] | clk_ibuf/I
0.952 | 0.952 | tINS | RR | 15774 | IOB117[B] | clk_ibuf/O
2.371 | 1.418 | tNET | RR | 1 | R30C8[1][A] | g_sound.u_calib1/rem_r_7_s1/CLK
2.323 | -0.048 | tHld | | 1 | R30C8[1][A] | g_sound.u_calib1/rem_r_7_s1

Path Statistics:

Clock Skew | 0.185
Hold Relationship | 0.000
Logic Level | 1
Arrival Clock Path Delay | cell: 0.952, 43.558%; route: 1.234, 56.442%
Arrival Data Path Delay | cell: 0.000, 0.000%; route: 0.895, 87.357%; tC2Q: 0.130, 12.643%
Required Clock Path Delay | cell: 0.952, 40.168%; route: 1.418, 59.832%

## Minimum Pulse Width Report:

#### Report Command:report_min_pulse_width -nworst 10 -detail

### MPW1

MPW Summary:

Slack: | 6.809
Actual Width: | 7.709
Required Width: | 0.900
Type: | Low Pulse Width
Clock: | clk_sys
Objects: | g_sound.u_looper/ep_mem_ep_mem_0_3_s

Late clock Path:

AT | DELAY | TYPE | RF | NODE
10.000 | 0.000 | | | active clock edge time
10.000 | 0.000 | | | clk_sys
10.000 | 0.000 | tCL | FF | clk_ibuf/I
11.376 | 1.376 | tINS | FF | clk_ibuf/O
14.661 | 3.285 | tNET | FF | g_sound.u_looper/ep_mem_ep_mem_0_3_s/CLKA

Early clock Path:

AT | DELAY | TYPE | RF | NODE
20.000 | 0.000 | | | active clock edge time
20.000 | 0.000 | | | clk_sys
20.000 | 0.000 | tCL | RR | clk_ibuf/I
20.952 | 0.952 | tINS | RR | clk_ibuf/O
22.371 | 1.418 | tNET | RR | g_sound.u_looper/ep_mem_ep_mem_0_3_s/CLKA

### MPW2

MPW Summary:

Slack: | 6.809
Actual Width: | 7.709
Required Width: | 0.900
Type: | Low Pulse Width
Clock: | clk_sys
Objects: | g_sound.u_looper/ep_mem_ep_mem_0_4_s

Late clock Path:

AT | DELAY | TYPE | RF | NODE
10.000 | 0.000 | | | active clock edge time
10.000 | 0.000 | | | clk_sys
10.000 | 0.000 | tCL | FF | clk_ibuf/I
11.376 | 1.376 | tINS | FF | clk_ibuf/O
14.661 | 3.285 | tNET | FF | g_sound.u_looper/ep_mem_ep_mem_0_4_s/CLKB

Early clock Path:

AT | DELAY | TYPE | RF | NODE
20.000 | 0.000 | | | active clock edge time
20.000 | 0.000 | | | clk_sys
20.000 | 0.000 | tCL | RR | clk_ibuf/I
20.952 | 0.952 | tINS | RR | clk_ibuf/O
22.371 | 1.418 | tNET | RR | g_sound.u_looper/ep_mem_ep_mem_0_4_s/CLKB

### MPW3

MPW Summary:

Slack: | 6.814
Actual Width: | 7.714
Required Width: | 0.900
Type: | Low Pulse Width
Clock: | clk_sys
Objects: | g_sound.u_looper/ep_mem_ep_mem_0_3_s

Late clock Path:

AT | DELAY | TYPE | RF | NODE
10.000 | 0.000 | | | active clock edge time
10.000 | 0.000 | | | clk_sys
10.000 | 0.000 | tCL | FF | clk_ibuf/I
11.376 | 1.376 | tINS | FF | clk_ibuf/O
14.653 | 3.277 | tNET | FF | g_sound.u_looper/ep_mem_ep_mem_0_3_s/CLKB

Early clock Path:

AT | DELAY | TYPE | RF | NODE
20.000 | 0.000 | | | active clock edge time
20.000 | 0.000 | | | clk_sys
20.000 | 0.000 | tCL | RR | clk_ibuf/I
20.952 | 0.952 | tINS | RR | clk_ibuf/O
22.367 | 1.415 | tNET | RR | g_sound.u_looper/ep_mem_ep_mem_0_3_s/CLKB

### MPW4

MPW Summary:

Slack: | 6.814
Actual Width: | 7.714
Required Width: | 0.900
Type: | Low Pulse Width
Clock: | clk_sys
Objects: | g_sound.u_looper/ep_mem_ep_mem_0_4_s

Late clock Path:

AT | DELAY | TYPE | RF | NODE
10.000 | 0.000 | | | active clock edge time
10.000 | 0.000 | | | clk_sys
10.000 | 0.000 | tCL | FF | clk_ibuf/I
11.376 | 1.376 | tINS | FF | clk_ibuf/O
14.653 | 3.277 | tNET | FF | g_sound.u_looper/ep_mem_ep_mem_0_4_s/CLKA

Early clock Path:

AT | DELAY | TYPE | RF | NODE
20.000 | 0.000 | | | active clock edge time
20.000 | 0.000 | | | clk_sys
20.000 | 0.000 | tCL | RR | clk_ibuf/I
20.952 | 0.952 | tINS | RR | clk_ibuf/O
22.367 | 1.415 | tNET | RR | g_sound.u_looper/ep_mem_ep_mem_0_4_s/CLKA

### MPW5

MPW Summary:

Slack: | 7.072
Actual Width: | 7.972
Required Width: | 0.900
Type: | Low Pulse Width
Clock: | clk_sys
Objects: | g_sound.u_envelope_bank/g_voice_envelope[6].u_adsr/n103_s

Late clock Path:

AT | DELAY | TYPE | RF | NODE
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

AT | DELAY | TYPE | RF | NODE
10.000 | 0.000 | | | active clock edge time
10.000 | 0.000 | | | clk_sys
10.000 | 0.000 | tCL | FF | clk_ibuf/I
11.376 | 1.376 | tINS | FF | clk_ibuf/O
14.216 | 2.839 | tNET | FF | g_sound.u_envelope_bank/g_voice_envelope[18].u_adsr/n103_s/CLK[0]

Early clock Path:

AT | DELAY | TYPE | RF | NODE
20.000 | 0.000 | | | active clock edge time
20.000 | 0.000 | | | clk_sys
20.000 | 0.000 | tCL | RR | clk_ibuf/I
20.952 | 0.952 | tINS | RR | clk_ibuf/O
22.193 | 1.241 | tNET | RR | g_sound.u_envelope_bank/g_voice_envelope[18].u_adsr/n103_s/CLK[0]

## High Fanout Nets Report:

#### Report Command:report_high_fanout_nets -max_nets 10

FANOUT | NET NAME | WORST SLACK | MAX DELAY
15774 | clk_d | 0.194 | 3.316
12951 | rst_n_sync | 0.669 | 2.337
1691 | tick_audio_Z | 12.484 | 2.159
1000 | g_sound.tm_enable_r_16 | 6.937 | 8.047
1000 | g_sound.tm_enable_r_18 | 10.286 | 5.660
892 | g_sound.tm_enable_r | 2.490 | 7.408
814 | g_sound.u_looper/ramp_sc[0] | 6.400 | 4.350
515 | g_sound.u_note_manager/scan_cnt[0] | 5.004 | 4.664
486 | g_sound.af_sample_ch[2] | 1.219 | 5.209
409 | g_sound.u_looper/ramp_sc[1] | 7.510 | 3.322

## Route Congestions Report:

#### Report Command:report_route_congestion -max_grids 10

GRID LOC | ROUTE CONGESTIONS
R22C131 | 91.67%
R14C122 | 90.28%
R13C122 | 90.28%
R13C121 | 88.89%
R25C96 | 87.50%
R16C110 | 87.50%
R32C96 | 87.50%
R13C110 | 86.11%
R14C120 | 86.11%
R13C117 | 86.11%

## Timing Exceptions Report:

### Setup Analysis Report

#### Report Command:report_exceptions -setup -max_paths 5 -max_common_paths 1

#### No timing exceptions to report!

### Hold Analysis Report

#### Report Command:report_exceptions -hold -max_paths 5 -max_common_paths 1

#### No timing exceptions to report!

### Recovery Analysis Report

#### Report Command:report_exceptions -recovery -max_paths 5 -max_common_paths 1

#### No timing exceptions to report!

### Removal Analysis Report

#### Report Command:report_exceptions -removal -max_paths 5 -max_common_paths 1

#### No timing exceptions to report!

## Timing Constraints Report:

SDC Command Type | State | Detail Command
TC_CLOCK | Actived | create_clock -name clk_sys -period 20 -waveform {0 10} [get_ports {clk}]
TC_GENERATED_CLOCK | Actived | create_generated_clock -name serial_clk -source [get_ports {clk}] -master_clock clk_sys -divide_by 8 -multiply_by 20 [get_pins {u_hdmi/u_clk/u_pll/CLKOUT0}]
TC_GENERATED_CLOCK | Actived | create_generated_clock -name pixel_clk -source [get_ports {clk}] -master_clock clk_sys -divide_by 40 -multiply_by 20 [get_pins {u_hdmi/u_clk/u_pll/CLKOUT1}]
TC_OUTPUT_DELAY | Actived | set_output_delay -clock clk_sys -max 2.0 [get_ports {HP_BCK}]
TC_OUTPUT_DELAY | Actived | set_output_delay -clock clk_sys -max 2.0 [get_ports {HP_WS}]
TC_OUTPUT_DELAY | Actived | set_output_delay -clock clk_sys -max 2.0 [get_ports {HP_DIN}]
TC_FALSE_PATH | Actived | set_false_path -to [get_ports {PA_EN_n}]
TC_FALSE_PATH | Actived | set_false_path -to [get_ports {led_heartbeat}]
TC_FALSE_PATH | Actived | set_false_path -from [get_ports {rst_n}]
