hokuu1102/Gowin2026-PolySynth/evidence/h5/build-initial-c2-hold11/main-timing.html

# Timing Messages

Report Title | Timing Analysis Report
Design File | C:\Users\cyx\Documents\ChatGPT\FPGA\Gowin2026-PolySynth-t31b-main\impl\gwsynthesis\Gowin2026.vg
Physical Constraints File | C:\Users\cyx\Documents\ChatGPT\FPGA\Gowin2026-PolySynth-t31b-main\constr\top.cst
Timing Constraint File | C:\Users\cyx\Documents\ChatGPT\FPGA\Gowin2026-PolySynth-t31b-main\constr\top.sdc
Tool Version | V1.9.12.03 (64-bit)
Part Number | GW5AT-LV60PG484AC2/I1
Device | GW5AT-60
Device Version | B
Created Time | Thu Oct 1 18:41:52 2026
Legal Announcement | Copyright (C)2014-2026 Gowin Semiconductor Corporation. All rights reserved.

# Timing Summaries

## STA Tool Run Summary:

Setup Delay Model | Slow 0.93V 0C C2/I1
Hold Delay Model | Fast 0.975V 85C C2/I1
Numbers of Paths Analyzed | 49751
Numbers of Endpoints Analyzed | 50625
Numbers of Falling Endpoints | 4
Numbers of Setup Violated Endpoints | 0
Numbers of Hold Violated Endpoints | 11

## Clock Summary:

NO. | Clock Name | Type | Period | Frequency(MHz) | Rise | Fall | Source | Master | Objects
1 | clk_sys | Base | 20.000 | 50.000 | 0.000 | 10.000 | | | clk
2 | serial_clk | Generated | 8.000 | 125.000 | 0.000 | 4.000 | clk | clk_sys | u_hdmi/u_clk/u_pll/CLKOUT0
3 | pixel_clk | Generated | 40.000 | 25.000 | 0.000 | 20.000 | clk | clk_sys | u_hdmi/u_clk/u_pll/CLKOUT1

## Max Frequency Summary:

NO. | Clock Name | Constraint | Actual Fmax | Logic Level | Entity
1 | clk_sys | 50.000(MHz) | 61.651(MHz) | 10 | TOP
2 | pixel_clk | 25.000(MHz) | 143.572(MHz) | 9 | TOP

#### No timing paths to get frequency of serial_clk!

## Total Negative Slack Summary:

Clock Name | Analysis Type | Endpoints TNS | Number of Endpoints
clk_sys | Setup | 0.000 | 0
clk_sys | Hold | 0.000 | 0
serial_clk | Setup | 0.000 | 0
serial_clk | Hold | 0.000 | 0
pixel_clk | Setup | 0.000 | 0
pixel_clk | Hold | 0.000 | 0

# Timing Details

## Path Slacks Table:

### Setup Paths Table

#### Report Command:report_timing -setup -max_paths 25 -max_common_paths 1

Path Number | Path Slack | From Node | To Node | From Clock | To Clock | Relation | Clock Skew | Data Delay
1 | 3.780 | g_sound.u_note_manager/env_active_r_1_s0/Q | g_sound.u_note_manager/scan_cnt_3_s0/CE | clk_sys:[R] | clk_sys:[R] | 20.000 | 0.363 | 15.633
2 | 3.780 | g_sound.u_note_manager/env_active_r_1_s0/Q | g_sound.u_note_manager/scan_cnt_4_s0/CE | clk_sys:[R] | clk_sys:[R] | 20.000 | 0.363 | 15.633
3 | 4.224 | g_sound.u_note_manager/env_active_r_1_s0/Q | g_sound.u_note_manager/scan_cnt_1_s0/CE | clk_sys:[R] | clk_sys:[R] | 20.000 | 0.363 | 15.188
4 | 4.441 | g_sound.u_seq_arb/cnt_q_0_s0/Q | g_sound.u_seq_arb/mem_mem_RAMREG_0_G[37]_s0/CE | clk_sys:[R] | clk_sys:[R] | 20.000 | 0.000 | 15.335
5 | 4.441 | g_sound.u_seq_arb/cnt_q_0_s0/Q | g_sound.u_seq_arb/mem_mem_RAMREG_0_G[35]_s0/CE | clk_sys:[R] | clk_sys:[R] | 20.000 | 0.000 | 15.335
6 | 4.441 | g_sound.u_seq_arb/cnt_q_0_s0/Q | g_sound.u_seq_arb/mem_mem_RAMREG_0_G[27]_s0/CE | clk_sys:[R] | clk_sys:[R] | 20.000 | 0.000 | 15.335
7 | 4.441 | g_sound.u_seq_arb/cnt_q_0_s0/Q | g_sound.u_seq_arb/mem_mem_RAMREG_0_G[25]_s0/CE | clk_sys:[R] | clk_sys:[R] | 20.000 | 0.000 | 15.335
8 | 4.473 | g_sound.u_evt_merge/cnt_q_0_s0/Q | g_sound.u_evt_merge/mem_mem_RAMREG_0_G[0]_s0/CE | clk_sys:[R] | clk_sys:[R] | 20.000 | 0.007 | 15.296
9 | 4.473 | g_sound.u_evt_merge/cnt_q_0_s0/Q | g_sound.u_evt_merge/mem_mem_RAMREG_0_G[12]_s0/CE | clk_sys:[R] | clk_sys:[R] | 20.000 | 0.007 | 15.296
10 | 4.488 | g_sound.u_seq_arb/cnt_q_0_s0/Q | g_sound.u_seq_arb/mem_mem_RAMREG_0_G[13]_s0/CE | clk_sys:[R] | clk_sys:[R] | 20.000 | 0.000 | 15.288
11 | 4.574 | g_sound.u_seq_arb/cnt_q_0_s0/Q | g_sound.u_seq_arb/mem_mem_RAMREG_4_G[48]_s0/RESET | clk_sys:[R] | clk_sys:[R] | 20.000 | 0.000 | 15.157
12 | 4.575 | g_sound.u_seq_arb/cnt_q_0_s0/Q | g_sound.u_seq_arb/mem_mem_RAMREG_0_G[46]_s0/CE | clk_sys:[R] | clk_sys:[R] | 20.000 | 0.007 | 15.194
13 | 4.575 | g_sound.u_seq_arb/cnt_q_0_s0/Q | g_sound.u_seq_arb/mem_mem_RAMREG_0_G[45]_s0/CE | clk_sys:[R] | clk_sys:[R] | 20.000 | 0.007 | 15.194
14 | 4.671 | g_sound.u_seq_arb/cnt_q_0_s0/Q | g_sound.u_seq_arb/mem_mem_RAMREG_4_G[1]_s0/RESET | clk_sys:[R] | clk_sys:[R] | 20.000 | 0.007 | 15.054
15 | 4.690 | g_sound.u_seq_arb/cnt_q_0_s0/Q | g_sound.u_seq_arb/mem_mem_RAMREG_6_G[32]_s0/CE | clk_sys:[R] | clk_sys:[R] | 20.000 | 0.000 | 15.086
16 | 4.708 | g_sound.u_note_manager/env_active_r_1_s0/Q | g_sound.u_note_manager/vtgt_vld_vtgt_vld_RAMREG_7_G[0]_s0/D | clk_sys:[R] | clk_sys:[R] | 20.000 | 0.350 | 14.733
17 | 4.722 | g_sound.u_seq_arb/cnt_q_0_s0/Q | g_sound.u_seq_arb/mem_mem_RAMREG_0_G[32]_s0/CE | clk_sys:[R] | clk_sys:[R] | 20.000 | 0.000 | 15.054
18 | 4.722 | g_sound.u_seq_arb/cnt_q_0_s0/Q | g_sound.u_seq_arb/mem_mem_RAMREG_0_G[31]_s0/CE | clk_sys:[R] | clk_sys:[R] | 20.000 | 0.000 | 15.054
19 | 4.722 | g_sound.u_seq_arb/cnt_q_0_s0/Q | g_sound.u_seq_arb/mem_mem_RAMREG_0_G[28]_s0/CE | clk_sys:[R] | clk_sys:[R] | 20.000 | 0.000 | 15.054
20 | 4.722 | g_sound.u_seq_arb/cnt_q_0_s0/Q | g_sound.u_seq_arb/mem_mem_RAMREG_0_G[20]_s0/CE | clk_sys:[R] | clk_sys:[R] | 20.000 | 0.000 | 15.054
21 | 4.724 | g_sound.u_evt_merge/cnt_q_0_s0/Q | g_sound.u_evt_merge/mem_mem_RAMREG_5_G[26]_s0/CE | clk_sys:[R] | clk_sys:[R] | 20.000 | 0.000 | 15.052
22 | 4.729 | g_sound.u_seq_arb/cnt_q_0_s0/Q | g_sound.u_seq_arb/mem_mem_RAMREG_0_G[12]_s0/CE | clk_sys:[R] | clk_sys:[R] | 20.000 | 0.000 | 15.047
23 | 4.731 | g_sound.u_seq_arb/cnt_q_0_s0/Q | g_sound.u_seq_arb/mem_mem_RAMREG_0_G[38]_s0/CE | clk_sys:[R] | clk_sys:[R] | 20.000 | 0.000 | 15.045
24 | 4.731 | g_sound.u_seq_arb/cnt_q_0_s0/Q | g_sound.u_seq_arb/mem_mem_RAMREG_0_G[36]_s0/CE | clk_sys:[R] | clk_sys:[R] | 20.000 | 0.000 | 15.045
25 | 4.734 | g_sound.u_seq_arb/cnt_q_0_s0/Q | g_sound.u_seq_arb/mem_mem_RAMREG_0_G[33]_s0/CE | clk_sys:[R] | clk_sys:[R] | 20.000 | -0.007 | 15.048

### Hold Paths Table

#### Report Command:report_timing -hold -max_paths 25 -max_common_paths 1

Path Number | Path Slack | From Node | To Node | From Clock | To Clock | Relation | Clock Skew | Data Delay
1 | -0.306 | u_hdmi/u_scope/wr_gray_0_s0/Q | u_hdmi/u_scope/gray_meta_0_s0/D | clk_sys:[R] | pixel_clk:[R] | 0.000 | -0.609 | 0.350
2 | -0.300 | u_hdmi/u_scope/wr_gray_7_s0/Q | u_hdmi/u_scope/gray_meta_7_s0/D | clk_sys:[R] | pixel_clk:[R] | 0.000 | -0.598 | 0.286
3 | -0.294 | u_hdmi/u_scope/wr_gray_1_s0/Q | u_hdmi/u_scope/gray_meta_1_s0/D | clk_sys:[R] | pixel_clk:[R] | 0.000 | -0.602 | 0.295
4 | -0.294 | u_hdmi/u_scope/wr_gray_2_s0/Q | u_hdmi/u_scope/gray_meta_2_s0/D | clk_sys:[R] | pixel_clk:[R] | 0.000 | -0.602 | 0.295
5 | -0.274 | u_hdmi/u_scope/wr_gray_9_s0/Q | u_hdmi/u_scope/gray_meta_9_s0/D | clk_sys:[R] | pixel_clk:[R] | 0.000 | -0.598 | 0.311
6 | -0.273 | u_hdmi/u_scope/wr_gray_4_s0/Q | u_hdmi/u_scope/gray_meta_4_s0/D | clk_sys:[R] | pixel_clk:[R] | 0.000 | -0.595 | 0.309
7 | -0.203 | u_hdmi/u_scope/history_full_s0/Q | u_hdmi/u_scope/full_meta_s0/D | clk_sys:[R] | pixel_clk:[R] | 0.000 | -0.602 | 0.386
8 | -0.203 | u_hdmi/u_scope/wr_gray_5_s0/Q | u_hdmi/u_scope/gray_meta_5_s0/D | clk_sys:[R] | pixel_clk:[R] | 0.000 | -0.602 | 0.386
9 | -0.203 | u_hdmi/u_scope/wr_gray_8_s0/Q | u_hdmi/u_scope/gray_meta_8_s0/D | clk_sys:[R] | pixel_clk:[R] | 0.000 | -0.602 | 0.386
10 | -0.119 | u_hdmi/u_scope/wr_gray_3_s0/Q | u_hdmi/u_scope/gray_meta_3_s0/D | clk_sys:[R] | pixel_clk:[R] | 0.000 | -0.598 | 0.526
11 | -0.033 | u_hdmi/u_scope/wr_gray_6_s0/Q | u_hdmi/u_scope/gray_meta_6_s0/D | clk_sys:[R] | pixel_clk:[R] | 0.000 | -0.595 | 0.608
12 | 0.056 | u_hdmi/u_scope/wr_ptr_4_s0/Q | u_hdmi/u_scope/history_history_0_0_s/ADA[8] | clk_sys:[R] | clk_sys:[R] | 0.000 | -0.181 | 0.270
13 | 0.127 | u_hdmi/u_scope/wr_ptr_3_s0/Q | u_hdmi/u_scope/history_history_0_0_s/ADA[7] | clk_sys:[R] | clk_sys:[R] | 0.000 | -0.177 | 0.337
14 | 0.129 | u_hdmi/u_scope/copy_index_q_1_s0/Q | u_hdmi/u_scope/frame_y_frame_y_0_0_s/ADA[4] | pixel_clk:[R] | pixel_clk:[R] | 0.000 | -0.177 | 0.339
15 | 0.132 | u_hdmi/u_scope/wr_ptr_2_s0/Q | u_hdmi/u_scope/history_history_0_0_s/ADA[6] | clk_sys:[R] | clk_sys:[R] | 0.000 | -0.177 | 0.343
16 | 0.134 | u_hdmi/u_scope/copy_index_q_3_s0/Q | u_hdmi/u_scope/frame_y_frame_y_0_0_s/ADA[6] | pixel_clk:[R] | pixel_clk:[R] | 0.000 | -0.177 | 0.345
17 | 0.136 | g_sound.u_looper/rd_ptr_r_6_s0/Q | g_sound.u_looper/mem_mem_0_4_s/ADB[9] | clk_sys:[R] | clk_sys:[R] | 0.000 | -0.174 | 0.341
18 | 0.153 | u_hdmi/u_timing/x_0_s0/Q | u_hdmi/u_scope/frame_y_frame_y_0_0_s/ADB[3] | pixel_clk:[R] | pixel_clk:[R] | 0.000 | -0.177 | 0.362
19 | 0.215 | u_hdmi/u_scope/wr_ptr_6_s0/Q | u_hdmi/u_scope/history_history_0_0_s/ADA[10] | clk_sys:[R] | clk_sys:[R] | 0.000 | -0.177 | 0.426
20 | 0.217 | u_hdmi/u_scope/copy_index_q_9_s0/Q | u_hdmi/u_scope/frame_y_frame_y_0_0_s/ADA[12] | pixel_clk:[R] | pixel_clk:[R] | 0.000 | -0.174 | 0.424
21 | 0.217 | u_hdmi/u_scope/copy_index_q_6_s0/Q | u_hdmi/u_scope/frame_y_frame_y_0_0_s/ADA[9] | pixel_clk:[R] | pixel_clk:[R] | 0.000 | -0.174 | 0.424
22 | 0.217 | u_hdmi/u_scope/copy_index_q_0_s0/Q | u_hdmi/u_scope/frame_y_frame_y_0_0_s/ADA[3] | pixel_clk:[R] | pixel_clk:[R] | 0.000 | -0.174 | 0.424
23 | 0.219 | u_hdmi/u_scope/copy_index_q_4_s0/Q | u_hdmi/u_scope/frame_y_frame_y_0_0_s/ADA[7] | pixel_clk:[R] | pixel_clk:[R] | 0.000 | -0.177 | 0.429
24 | 0.245 | g_sound.u_evt_merge/head_q_15_s0/Q | g_sound.u_evt_merge/head_q_15_s0/D | clk_sys:[R] | clk_sys:[R] | 0.000 | 0.000 | 0.267
25 | 0.247 | u_led_bank/u_driver/bit_index_2_s0/Q | u_led_bank/u_driver/bit_index_2_s0/D | clk_sys:[R] | clk_sys:[R] | 0.000 | 0.000 | 0.270

### Recovery Paths Table

#### Report Command:report_timing -recovery -max_paths 25 -max_common_paths 1

Path Number | Path Slack | From Node | To Node | From Clock | To Clock | Relation | Clock Skew | Data Delay
1 | 1.417 | u_rst_sync/sync_chain_1_s0/Q | u_hdmi/u_serializer/lanes[3].u_oser/RESET | clk_sys:[R] | serial_clk:[R] | 4.000 | 0.007 | 2.423
2 | 1.417 | u_rst_sync/sync_chain_1_s0/Q | u_hdmi/u_serializer/lanes[2].u_oser/RESET | clk_sys:[R] | serial_clk:[R] | 4.000 | 0.007 | 2.423
3 | 1.417 | u_rst_sync/sync_chain_1_s0/Q | u_hdmi/u_serializer/lanes[1].u_oser/RESET | clk_sys:[R] | serial_clk:[R] | 4.000 | 0.007 | 2.423
4 | 1.417 | u_rst_sync/sync_chain_1_s0/Q | u_hdmi/u_serializer/lanes[0].u_oser/RESET | clk_sys:[R] | serial_clk:[R] | 4.000 | 0.007 | 2.423
5 | 1.418 | u_rst_sync/sync_chain_1_s0/Q | u_hdmi/u_serializer/lanes[0].u_oser/RESET | clk_sys:[R] | serial_clk:[F] | 4.000 | 0.007 | 2.423
6 | 1.418 | u_rst_sync/sync_chain_1_s0/Q | u_hdmi/u_serializer/lanes[1].u_oser/RESET | clk_sys:[R] | serial_clk:[F] | 4.000 | 0.007 | 2.423
7 | 1.418 | u_rst_sync/sync_chain_1_s0/Q | u_hdmi/u_serializer/lanes[2].u_oser/RESET | clk_sys:[R] | serial_clk:[F] | 4.000 | 0.007 | 2.423
8 | 1.418 | u_rst_sync/sync_chain_1_s0/Q | u_hdmi/u_serializer/lanes[3].u_oser/RESET | clk_sys:[R] | serial_clk:[F] | 4.000 | 0.007 | 2.423
9 | 15.401 | u_rst_sync/sync_chain_1_s0/Q | g_sound.u_calib0/n840_s/RESET[0] | clk_sys:[R] | clk_sys:[R] | 20.000 | 0.007 | 4.188
10 | 16.079 | u_rst_sync/sync_chain_1_s0/Q | g_sound.u_calib1/n840_s/RESET[0] | clk_sys:[R] | clk_sys:[R] | 20.000 | 0.000 | 3.517
11 | 17.316 | u_rst_sync/sync_chain_1_s0/Q | g_sound.u_looper/play_upd_inc_o_28_s0/CLEAR | clk_sys:[R] | clk_sys:[R] | 20.000 | 0.007 | 2.427
12 | 17.320 | u_rst_sync/sync_chain_1_s0/Q | g_sound.u_looper/leave_to_r_0_s3/CLEAR | clk_sys:[R] | clk_sys:[R] | 20.000 | 0.007 | 2.423
13 | 17.320 | u_rst_sync/sync_chain_1_s0/Q | g_sound.u_looper/leave_to_r_1_s7/CLEAR | clk_sys:[R] | clk_sys:[R] | 20.000 | 0.007 | 2.423
14 | 17.320 | u_rst_sync/sync_chain_1_s0/Q | g_sound.u_looper/ramp_vel[13]_1_s1/CLEAR | clk_sys:[R] | clk_sys:[R] | 20.000 | 0.007 | 2.423
15 | 17.320 | u_rst_sync/sync_chain_1_s0/Q | g_sound.u_looper/ramp_vel[13]_2_s1/CLEAR | clk_sys:[R] | clk_sys:[R] | 20.000 | 0.007 | 2.423
16 | 17.320 | u_rst_sync/sync_chain_1_s0/Q | g_sound.u_looper/ramp_vel[13]_3_s1/CLEAR | clk_sys:[R] | clk_sys:[R] | 20.000 | 0.007 | 2.423
17 | 17.320 | u_rst_sync/sync_chain_1_s0/Q | g_sound.u_looper/ramp_vel[12]_2_s1/CLEAR | clk_sys:[R] | clk_sys:[R] | 20.000 | 0.007 | 2.423
18 | 17.320 | u_rst_sync/sync_chain_1_s0/Q | g_sound.u_looper/ramp_vel[12]_3_s1/CLEAR | clk_sys:[R] | clk_sys:[R] | 20.000 | 0.007 | 2.423
19 | 17.320 | u_rst_sync/sync_chain_1_s0/Q | g_sound.u_looper/ramp_vel[12]_7_s1/CLEAR | clk_sys:[R] | clk_sys:[R] | 20.000 | 0.007 | 2.423
20 | 17.320 | u_rst_sync/sync_chain_1_s0/Q | g_sound.u_looper/ramp_vel[11]_1_s1/CLEAR | clk_sys:[R] | clk_sys:[R] | 20.000 | 0.007 | 2.423
21 | 17.320 | u_rst_sync/sync_chain_1_s0/Q | g_sound.u_looper/ramp_vel[10]_0_s1/CLEAR | clk_sys:[R] | clk_sys:[R] | 20.000 | 0.007 | 2.423
22 | 17.320 | u_rst_sync/sync_chain_1_s0/Q | g_sound.u_looper/ramp_vel[10]_1_s1/CLEAR | clk_sys:[R] | clk_sys:[R] | 20.000 | 0.007 | 2.423
23 | 17.320 | u_rst_sync/sync_chain_1_s0/Q | g_sound.u_looper/ramp_vel[10]_6_s1/CLEAR | clk_sys:[R] | clk_sys:[R] | 20.000 | 0.007 | 2.423
24 | 17.320 | u_rst_sync/sync_chain_1_s0/Q | g_sound.u_looper/ramp_vel[10]_7_s1/CLEAR | clk_sys:[R] | clk_sys:[R] | 20.000 | 0.007 | 2.423
25 | 17.320 | u_rst_sync/sync_chain_1_s0/Q | g_sound.u_looper/ramp_vel[8]_4_s1/CLEAR | clk_sys:[R] | clk_sys:[R] | 20.000 | 0.007 | 2.423

### Removal Paths Table

#### Report Command:report_timing -removal -max_paths 25 -max_common_paths 1

Path Number | Path Slack | From Node | To Node | From Clock | To Clock | Relation | Clock Skew | Data Delay
1 | 0.416 | u_rst_sync/sync_chain_1_s0/Q | u_hdmi/u_serializer/lanes[3].u_oser/RESET | clk_sys:[R] | pixel_clk:[R] | 0.000 | -0.609 | 1.179
2 | 0.416 | u_rst_sync/sync_chain_1_s0/Q | u_hdmi/u_serializer/lanes[2].u_oser/RESET | clk_sys:[R] | pixel_clk:[R] | 0.000 | -0.609 | 1.179
3 | 0.416 | u_rst_sync/sync_chain_1_s0/Q | u_hdmi/u_serializer/lanes[1].u_oser/RESET | clk_sys:[R] | pixel_clk:[R] | 0.000 | -0.609 | 1.179
4 | 0.416 | u_rst_sync/sync_chain_1_s0/Q | u_hdmi/u_serializer/lanes[0].u_oser/RESET | clk_sys:[R] | pixel_clk:[R] | 0.000 | -0.609 | 1.179
5 | 0.582 | u_rst_sync/sync_chain_1_s0/Q | u_hdmi/reset_pipe_1_s0/CLEAR | clk_sys:[R] | pixel_clk:[R] | 0.000 | -0.606 | 1.175
6 | 0.582 | u_rst_sync/sync_chain_1_s0/Q | u_hdmi/reset_pipe_0_s0/CLEAR | clk_sys:[R] | pixel_clk:[R] | 0.000 | -0.606 | 1.175
7 | 1.029 | u_rst_sync/sync_chain_1_s0/Q | u_hdmi/u_serializer/lanes[0].u_oser/RESET | clk_sys:[R] | serial_clk:[R] | 0.000 | 0.004 | 1.179
8 | 1.029 | u_rst_sync/sync_chain_1_s0/Q | u_hdmi/u_serializer/lanes[1].u_oser/RESET | clk_sys:[R] | serial_clk:[R] | 0.000 | 0.004 | 1.179
9 | 1.029 | u_rst_sync/sync_chain_1_s0/Q | u_hdmi/u_serializer/lanes[2].u_oser/RESET | clk_sys:[R] | serial_clk:[R] | 0.000 | 0.004 | 1.179
10 | 1.029 | u_rst_sync/sync_chain_1_s0/Q | u_hdmi/u_serializer/lanes[3].u_oser/RESET | clk_sys:[R] | serial_clk:[R] | 0.000 | 0.004 | 1.179
11 | 1.030 | u_rst_sync/sync_chain_1_s0/Q | u_hdmi/u_serializer/lanes[0].u_oser/RESET | clk_sys:[R] | serial_clk:[F] | 0.000 | 0.004 | 1.179
12 | 1.030 | u_rst_sync/sync_chain_1_s0/Q | u_hdmi/u_serializer/lanes[1].u_oser/RESET | clk_sys:[R] | serial_clk:[F] | 0.000 | 0.004 | 1.179
13 | 1.030 | u_rst_sync/sync_chain_1_s0/Q | u_hdmi/u_serializer/lanes[2].u_oser/RESET | clk_sys:[R] | serial_clk:[F] | 0.000 | 0.004 | 1.179
14 | 1.030 | u_rst_sync/sync_chain_1_s0/Q | u_hdmi/u_serializer/lanes[3].u_oser/RESET | clk_sys:[R] | serial_clk:[F] | 0.000 | 0.004 | 1.179
15 | 1.055 | u_rst_sync/sync_chain_1_s0/Q | g_sound.u_calib0/ch_r_0_s0/CLEAR | clk_sys:[R] | clk_sys:[R] | 0.000 | -0.177 | 1.184
16 | 1.055 | u_rst_sync/sync_chain_1_s0/Q | g_sound.u_calib0/ch_r_1_s0/CLEAR | clk_sys:[R] | clk_sys:[R] | 0.000 | -0.177 | 1.184
17 | 1.055 | u_rst_sync/sync_chain_1_s0/Q | g_sound.u_calib0/ch_r_2_s0/CLEAR | clk_sys:[R] | clk_sys:[R] | 0.000 | -0.177 | 1.184
18 | 1.055 | u_rst_sync/sync_chain_1_s0/Q | g_sound.u_calib0/v_r_s0/CLEAR | clk_sys:[R] | clk_sys:[R] | 0.000 | -0.177 | 1.184
19 | 1.216 | u_rst_sync/sync_chain_1_s0/Q | g_sound.u_looper/ramp_vel[14]_0_s1/CLEAR | clk_sys:[R] | clk_sys:[R] | 0.000 | -0.004 | 1.172
20 | 1.216 | u_rst_sync/sync_chain_1_s0/Q | g_sound.u_looper/ramp_vel[14]_1_s1/CLEAR | clk_sys:[R] | clk_sys:[R] | 0.000 | -0.004 | 1.172
21 | 1.216 | u_rst_sync/sync_chain_1_s0/Q | g_sound.u_looper/ramp_vel[14]_2_s1/CLEAR | clk_sys:[R] | clk_sys:[R] | 0.000 | -0.004 | 1.172
22 | 1.216 | u_rst_sync/sync_chain_1_s0/Q | g_sound.u_looper/ramp_vel[14]_3_s1/CLEAR | clk_sys:[R] | clk_sys:[R] | 0.000 | -0.004 | 1.172
23 | 1.216 | u_rst_sync/sync_chain_1_s0/Q | g_sound.u_looper/ramp_vel[14]_4_s1/CLEAR | clk_sys:[R] | clk_sys:[R] | 0.000 | -0.004 | 1.172
24 | 1.216 | u_rst_sync/sync_chain_1_s0/Q | g_sound.u_looper/ramp_vel[14]_5_s1/CLEAR | clk_sys:[R] | clk_sys:[R] | 0.000 | -0.004 | 1.172
25 | 1.216 | u_rst_sync/sync_chain_1_s0/Q | g_sound.u_looper/ramp_vel[14]_6_s1/CLEAR | clk_sys:[R] | clk_sys:[R] | 0.000 | -0.004 | 1.172

## Minimum Pulse Width Table:

Number | Slack | Actual Width | Required Width | Type | Clock | Objects

#### Report Command:report_min_pulse_width -nworst 10 -detail

1 | 7.594 | 8.369 | 0.776 | Low Pulse Width | clk_sys | u_hdmi/u_scope/history_history_0_0_s
2 | 7.594 | 8.369 | 0.776 | Low Pulse Width | clk_sys | g_sound.u_looper/mem_mem_0_3_s
3 | 7.594 | 8.369 | 0.776 | Low Pulse Width | clk_sys | g_sound.u_looper/mem_mem_0_4_s
4 | 7.597 | 8.373 | 0.776 | Low Pulse Width | clk_sys | g_sound.u_looper/mem_mem_0_3_s
5 | 7.597 | 8.373 | 0.776 | Low Pulse Width | clk_sys | g_sound.u_looper/mem_mem_0_4_s
6 | 7.766 | 8.542 | 0.776 | Low Pulse Width | clk_sys | g_sound.u_tdm_render_mixer/mult_14924_0_s
7 | 7.766 | 8.542 | 0.776 | Low Pulse Width | clk_sys | g_sound.u_tdm_render_mixer/mult_14936_0_s
8 | 7.769 | 8.545 | 0.776 | Low Pulse Width | clk_sys | g_sound.u_tdm_render_mixer/mult_1149_s2
9 | 7.769 | 8.545 | 0.776 | Low Pulse Width | clk_sys | g_sound.u_tdm_render_mixer/mult_14926_0_s
10 | 7.769 | 8.545 | 0.776 | Low Pulse Width | clk_sys | g_sound.u_tdm_render_mixer/mult_14934_0_s

## Timing Report By Analysis Type:

### Setup Analysis Report

#### Report Command:report_timing -setup -max_paths 25 -max_common_paths 1

### Path1

Path Summary:

Slack | 3.780
Data Arrival Time | 19.561
Data Required Time | 23.340
From | g_sound.u_note_manager/env_active_r_1_s0
To | g_sound.u_note_manager/scan_cnt_3_s0
Launch Clk | clk_sys:[R]
Latch Clk | clk_sys:[R]

Data Arrival Path:

AT | DELAY | TYPE | RF | FANOUT | LOC | NODE
0.000 | 0.000 | | | | | active clock edge time
0.000 | 0.000 | | | | | clk_sys
0.000 | 0.000 | tCL | RR | 1 | IOB117[B] | clk_ibuf/I
1.288 | 1.288 | tINS | RR | 15763 | IOB117[B] | clk_ibuf/O
3.928 | 2.639 | tNET | RR | 1 | R36C13[0][A] | g_sound.u_note_manager/env_active_r_1_s0/CLK
4.203 | 0.275 | tC2Q | RR | 3 | R36C13[0][A] | g_sound.u_note_manager/env_active_r_1_s0/Q
9.473 | 5.270 | tNET | RR | 1 | R31C126[2][A] | g_sound.u_note_manager/cand_free_s63/I2
9.805 | 0.332 | tINS | RR | 10 | R31C126[2][A] | g_sound.u_note_manager/cand_free_s63/F
11.730 | 1.924 | tNET | RR | 1 | R17C134[2][A] | g_sound.u_note_manager/same_idx_0_s4/I2
12.109 | 0.379 | tINS | RR | 3 | R17C134[2][A] | g_sound.u_note_manager/same_idx_0_s4/F
12.706 | 0.598 | tNET | RR | 1 | R17C122[3][B] | g_sound.u_note_manager/same_idx_1_s19/I0
13.081 | 0.375 | tINS | RR | 3 | R17C122[3][B] | g_sound.u_note_manager/same_idx_1_s19/F
13.724 | 0.643 | tNET | RR | 1 | R17C115[1][A] | g_sound.u_note_manager/same_idx_3_s12/I2
14.103 | 0.379 | tINS | RR | 3 | R17C115[1][A] | g_sound.u_note_manager/same_idx_3_s12/F
14.108 | 0.005 | tNET | RR | 1 | R17C115[2][B] | g_sound.u_note_manager/same_valid_s4/I0
14.297 | 0.189 | tINS | RR | 1 | R17C115[2][B] | g_sound.u_note_manager/same_valid_s4/F
14.548 | 0.250 | tNET | RR | 1 | R16C116[3][B] | g_sound.u_note_manager/same_valid_s0/I3
14.923 | 0.375 | tINS | RR | 4 | R16C116[3][B] | g_sound.u_note_manager/same_valid_s0/F
15.504 | 0.581 | tNET | RR | 1 | R16C131[3][B] | g_sound.u_note_manager/n22713_s10/I2
15.862 | 0.358 | tINS | RR | 4 | R16C131[3][B] | g_sound.u_note_manager/n22713_s10/F
17.185 | 1.323 | tNET | RR | 1 | R7C118[1][A] | g_sound.u_note_manager/scan_cnt_4_s5/I1
17.564 | 0.379 | tINS | RR | 1 | R7C118[1][A] | g_sound.u_note_manager/scan_cnt_4_s5/F
17.566 | 0.002 | tNET | RR | 1 | R7C118[0][B] | g_sound.u_note_manager/scan_cnt_4_s6/I0
17.755 | 0.189 | tINS | RR | 5 | R7C118[0][B] | g_sound.u_note_manager/scan_cnt_4_s6/F
19.561 | 1.805 | tNET | RR | 1 | R30C99[2][B] | g_sound.u_note_manager/scan_cnt_3_s0/CE

Data Required Path:

AT | DELAY | TYPE | RF | FANOUT | LOC | NODE
20.000 | 20.000 | | | | | active clock edge time
20.000 | 0.000 | | | | | clk_sys
20.000 | 0.000 | tCL | RR | 1 | IOB117[B] | clk_ibuf/I
21.288 | 1.288 | tINS | RR | 15763 | IOB117[B] | clk_ibuf/O
23.564 | 2.276 | tNET | RR | 1 | R30C99[2][B] | g_sound.u_note_manager/scan_cnt_3_s0/CLK
23.340 | -0.224 | tSu | | 1 | R30C99[2][B] | g_sound.u_note_manager/scan_cnt_3_s0

Path Statistics:

Clock Skew | -0.363
Setup Relationship | 20.000
Logic Level | 10
Arrival Clock Path Delay | cell: 1.288, 32.802%; route: 2.639, 67.198%
Arrival Data Path Delay | cell: 2.956, 18.906%; route: 12.402, 79.332%; tC2Q: 0.275, 1.762%
Required Clock Path Delay | cell: 1.288, 36.144%; route: 2.276, 63.856%

### Path2

Path Summary:

Slack | 3.780
Data Arrival Time | 19.561
Data Required Time | 23.340
From | g_sound.u_note_manager/env_active_r_1_s0
To | g_sound.u_note_manager/scan_cnt_4_s0
Launch Clk | clk_sys:[R]
Latch Clk | clk_sys:[R]

Data Arrival Path:

AT | DELAY | TYPE | RF | FANOUT | LOC | NODE
0.000 | 0.000 | | | | | active clock edge time
0.000 | 0.000 | | | | | clk_sys
0.000 | 0.000 | tCL | RR | 1 | IOB117[B] | clk_ibuf/I
1.288 | 1.288 | tINS | RR | 15763 | IOB117[B] | clk_ibuf/O
3.928 | 2.639 | tNET | RR | 1 | R36C13[0][A] | g_sound.u_note_manager/env_active_r_1_s0/CLK
4.203 | 0.275 | tC2Q | RR | 3 | R36C13[0][A] | g_sound.u_note_manager/env_active_r_1_s0/Q
9.473 | 5.270 | tNET | RR | 1 | R31C126[2][A] | g_sound.u_note_manager/cand_free_s63/I2
9.805 | 0.332 | tINS | RR | 10 | R31C126[2][A] | g_sound.u_note_manager/cand_free_s63/F
11.730 | 1.924 | tNET | RR | 1 | R17C134[2][A] | g_sound.u_note_manager/same_idx_0_s4/I2
12.109 | 0.379 | tINS | RR | 3 | R17C134[2][A] | g_sound.u_note_manager/same_idx_0_s4/F
12.706 | 0.598 | tNET | RR | 1 | R17C122[3][B] | g_sound.u_note_manager/same_idx_1_s19/I0
13.081 | 0.375 | tINS | RR | 3 | R17C122[3][B] | g_sound.u_note_manager/same_idx_1_s19/F
13.724 | 0.643 | tNET | RR | 1 | R17C115[1][A] | g_sound.u_note_manager/same_idx_3_s12/I2
14.103 | 0.379 | tINS | RR | 3 | R17C115[1][A] | g_sound.u_note_manager/same_idx_3_s12/F
14.108 | 0.005 | tNET | RR | 1 | R17C115[2][B] | g_sound.u_note_manager/same_valid_s4/I0
14.297 | 0.189 | tINS | RR | 1 | R17C115[2][B] | g_sound.u_note_manager/same_valid_s4/F
14.548 | 0.250 | tNET | RR | 1 | R16C116[3][B] | g_sound.u_note_manager/same_valid_s0/I3
14.923 | 0.375 | tINS | RR | 4 | R16C116[3][B] | g_sound.u_note_manager/same_valid_s0/F
15.504 | 0.581 | tNET | RR | 1 | R16C131[3][B] | g_sound.u_note_manager/n22713_s10/I2
15.862 | 0.358 | tINS | RR | 4 | R16C131[3][B] | g_sound.u_note_manager/n22713_s10/F
17.185 | 1.323 | tNET | RR | 1 | R7C118[1][A] | g_sound.u_note_manager/scan_cnt_4_s5/I1
17.564 | 0.379 | tINS | RR | 1 | R7C118[1][A] | g_sound.u_note_manager/scan_cnt_4_s5/F
17.566 | 0.002 | tNET | RR | 1 | R7C118[0][B] | g_sound.u_note_manager/scan_cnt_4_s6/I0
17.755 | 0.189 | tINS | RR | 5 | R7C118[0][B] | g_sound.u_note_manager/scan_cnt_4_s6/F
19.561 | 1.805 | tNET | RR | 1 | R31C99[0][B] | g_sound.u_note_manager/scan_cnt_4_s0/CE

Data Required Path:

AT | DELAY | TYPE | RF | FANOUT | LOC | NODE
20.000 | 20.000 | | | | | active clock edge time
20.000 | 0.000 | | | | | clk_sys
20.000 | 0.000 | tCL | RR | 1 | IOB117[B] | clk_ibuf/I
21.288 | 1.288 | tINS | RR | 15763 | IOB117[B] | clk_ibuf/O
23.564 | 2.276 | tNET | RR | 1 | R31C99[0][B] | g_sound.u_note_manager/scan_cnt_4_s0/CLK
23.340 | -0.224 | tSu | | 1 | R31C99[0][B] | g_sound.u_note_manager/scan_cnt_4_s0

Path Statistics:

Clock Skew | -0.363
Setup Relationship | 20.000
Logic Level | 10
Arrival Clock Path Delay | cell: 1.288, 32.802%; route: 2.639, 67.198%
Arrival Data Path Delay | cell: 2.956, 18.906%; route: 12.402, 79.332%; tC2Q: 0.275, 1.762%
Required Clock Path Delay | cell: 1.288, 36.144%; route: 2.276, 63.856%

### Path3

Path Summary:

Slack | 4.224
Data Arrival Time | 19.116
Data Required Time | 23.340
From | g_sound.u_note_manager/env_active_r_1_s0
To | g_sound.u_note_manager/scan_cnt_1_s0
Launch Clk | clk_sys:[R]
Latch Clk | clk_sys:[R]

Data Arrival Path:

AT | DELAY | TYPE | RF | FANOUT | LOC | NODE
0.000 | 0.000 | | | | | active clock edge time
0.000 | 0.000 | | | | | clk_sys
0.000 | 0.000 | tCL | RR | 1 | IOB117[B] | clk_ibuf/I
1.288 | 1.288 | tINS | RR | 15763 | IOB117[B] | clk_ibuf/O
3.928 | 2.639 | tNET | RR | 1 | R36C13[0][A] | g_sound.u_note_manager/env_active_r_1_s0/CLK
4.203 | 0.275 | tC2Q | RR | 3 | R36C13[0][A] | g_sound.u_note_manager/env_active_r_1_s0/Q
9.473 | 5.270 | tNET | RR | 1 | R31C126[2][A] | g_sound.u_note_manager/cand_free_s63/I2
9.805 | 0.332 | tINS | RR | 10 | R31C126[2][A] | g_sound.u_note_manager/cand_free_s63/F
11.730 | 1.924 | tNET | RR | 1 | R17C134[2][A] | g_sound.u_note_manager/same_idx_0_s4/I2
12.109 | 0.379 | tINS | RR | 3 | R17C134[2][A] | g_sound.u_note_manager/same_idx_0_s4/F
12.706 | 0.598 | tNET | RR | 1 | R17C122[3][B] | g_sound.u_note_manager/same_idx_1_s19/I0
13.081 | 0.375 | tINS | RR | 3 | R17C122[3][B] | g_sound.u_note_manager/same_idx_1_s19/F
13.724 | 0.643 | tNET | RR | 1 | R17C115[1][A] | g_sound.u_note_manager/same_idx_3_s12/I2
14.103 | 0.379 | tINS | RR | 3 | R17C115[1][A] | g_sound.u_note_manager/same_idx_3_s12/F
14.108 | 0.005 | tNET | RR | 1 | R17C115[2][B] | g_sound.u_note_manager/same_valid_s4/I0
14.297 | 0.189 | tINS | RR | 1 | R17C115[2][B] | g_sound.u_note_manager/same_valid_s4/F
14.548 | 0.250 | tNET | RR | 1 | R16C116[3][B] | g_sound.u_note_manager/same_valid_s0/I3
14.923 | 0.375 | tINS | RR | 4 | R16C116[3][B] | g_sound.u_note_manager/same_valid_s0/F
15.504 | 0.581 | tNET | RR | 1 | R16C131[3][B] | g_sound.u_note_manager/n22713_s10/I2
15.862 | 0.358 | tINS | RR | 4 | R16C131[3][B] | g_sound.u_note_manager/n22713_s10/F
17.185 | 1.323 | tNET | RR | 1 | R7C118[1][A] | g_sound.u_note_manager/scan_cnt_4_s5/I1
17.564 | 0.379 | tINS | RR | 1 | R7C118[1][A] | g_sound.u_note_manager/scan_cnt_4_s5/F
17.566 | 0.002 | tNET | RR | 1 | R7C118[0][B] | g_sound.u_note_manager/scan_cnt_4_s6/I0
17.755 | 0.189 | tINS | RR | 5 | R7C118[0][B] | g_sound.u_note_manager/scan_cnt_4_s6/F
19.116 | 1.361 | tNET | RR | 1 | R30C131[2][A] | g_sound.u_note_manager/scan_cnt_1_s0/CE

Data Required Path:

AT | DELAY | TYPE | RF | FANOUT | LOC | NODE
20.000 | 20.000 | | | | | active clock edge time
20.000 | 0.000 | | | | | clk_sys
20.000 | 0.000 | tCL | RR | 1 | IOB117[B] | clk_ibuf/I
21.288 | 1.288 | tINS | RR | 15763 | IOB117[B] | clk_ibuf/O
23.564 | 2.276 | tNET | RR | 1 | R30C131[2][A] | g_sound.u_note_manager/scan_cnt_1_s0/CLK
23.340 | -0.224 | tSu | | 1 | R30C131[2][A] | g_sound.u_note_manager/scan_cnt_1_s0

Path Statistics:

Clock Skew | -0.363
Setup Relationship | 20.000
Logic Level | 10
Arrival Clock Path Delay | cell: 1.288, 32.802%; route: 2.639, 67.198%
Arrival Data Path Delay | cell: 2.956, 19.460%; route: 11.957, 78.727%; tC2Q: 0.275, 1.813%
Required Clock Path Delay | cell: 1.288, 36.144%; route: 2.276, 63.856%

### Path4

Path Summary:

Slack | 4.441
Data Arrival Time | 18.906
Data Required Time | 23.347
From | g_sound.u_seq_arb/cnt_q_0_s0
To | g_sound.u_seq_arb/mem_mem_RAMREG_0_G[37]_s0
Launch Clk | clk_sys:[R]
Latch Clk | clk_sys:[R]

Data Arrival Path:

AT | DELAY | TYPE | RF | FANOUT | LOC | NODE
0.000 | 0.000 | | | | | active clock edge time
0.000 | 0.000 | | | | | clk_sys
0.000 | 0.000 | tCL | RR | 1 | IOB117[B] | clk_ibuf/I
1.288 | 1.288 | tINS | RR | 15763 | IOB117[B] | clk_ibuf/O
3.571 | 2.283 | tNET | RR | 1 | R45C51[0][B] | g_sound.u_seq_arb/cnt_q_0_s0/CLK
3.847 | 0.275 | tC2Q | RR | 6 | R45C51[0][B] | g_sound.u_seq_arb/cnt_q_0_s0/Q
4.243 | 0.396 | tNET | RR | 1 | R46C53[0][A] | g_sound.u_seq_arb/cnt_after_pop_5_s1/I0
4.575 | 0.332 | tINS | RR | 5 | R46C53[0][A] | g_sound.u_seq_arb/cnt_after_pop_5_s1/F
4.889 | 0.314 | tNET | RR | 1 | R48C54[2][B] | g_sound.u_seq_arb/cnt_after_pop_8_s1/I3
5.078 | 0.189 | tINS | RR | 5 | R48C54[2][B] | g_sound.u_seq_arb/cnt_after_pop_8_s1/F
5.419 | 0.341 | tNET | RR | 1 | R46C53[3][B] | g_sound.u_seq_arb/cnt_after_pop_11_s1/I3
5.777 | 0.358 | tINS | RR | 5 | R46C53[3][B] | g_sound.u_seq_arb/cnt_after_pop_11_s1/F
6.130 | 0.353 | tNET | RR | 1 | R44C54[2][B] | g_sound.u_seq_arb/cnt_after_pop_13_s2/I3
6.462 | 0.332 | tINS | RR | 5 | R44C54[2][B] | g_sound.u_seq_arb/cnt_after_pop_13_s2/F
6.854 | 0.392 | tNET | RR | 1 | R45C52[1][A] | g_sound.u_seq_arb/pop_now_s2/I3
7.186 | 0.332 | tINS | RR | 82 | R45C52[1][A] | g_sound.u_seq_arb/pop_now_s2/F
10.110 | 2.924 | tNET | RR | 1 | R48C54[3][B] | g_sound.u_seq_arb/cnt_after_pop_6_s1/I3
10.485 | 0.375 | tINS | RR | 2 | R48C54[3][B] | g_sound.u_seq_arb/cnt_after_pop_6_s1/F
10.489 | 0.004 | tNET | RR | 1 | R48C54[1][B] | g_sound.u_seq_arb/cnt_after_pop_6_s0/I0
10.868 | 0.379 | tINS | RR | 1 | R48C54[1][B] | g_sound.u_seq_arb/cnt_after_pop_6_s0/F
11.313 | 0.446 | tNET | RR | 2 | R45C55[0][A] | g_sound.u_seq_arb/cnt_next_6_s/I1
11.668 | 0.355 | tINS | RR | 1 | R45C55[0][A] | g_sound.u_seq_arb/cnt_next_6_s/COUT
11.668 | 0.000 | tNET | RR | 2 | R45C55[0][B] | g_sound.u_seq_arb/cnt_next_7_s/CIN
11.704 | 0.036 | tINS | RR | 1 | R45C55[0][B] | g_sound.u_seq_arb/cnt_next_7_s/COUT
11.704 | 0.000 | tNET | RR | 2 | R45C55[1][A] | g_sound.u_seq_arb/cnt_next_8_s/CIN
11.740 | 0.036 | tINS | RR | 1 | R45C55[1][A] | g_sound.u_seq_arb/cnt_next_8_s/COUT
11.740 | 0.000 | tNET | RR | 2 | R45C55[1][B] | g_sound.u_seq_arb/cnt_next_9_s/CIN
11.776 | 0.036 | tINS | RR | 1 | R45C55[1][B] | g_sound.u_seq_arb/cnt_next_9_s/COUT
11.776 | 0.000 | tNET | RR | 2 | R45C55[2][A] | g_sound.u_seq_arb/cnt_next_10_s/CIN
11.812 | 0.036 | tINS | RR | 1 | R45C55[2][A] | g_sound.u_seq_arb/cnt_next_10_s/COUT
11.812 | 0.000 | tNET | RR | 2 | R45C55[2][B] | g_sound.u_seq_arb/cnt_next_11_s/CIN
11.848 | 0.036 | tINS | RR | 1 | R45C55[2][B] | g_sound.u_seq_arb/cnt_next_11_s/COUT
11.848 | 0.000 | tNET | RR | 2 | R45C56[0][A] | g_sound.u_seq_arb/cnt_next_12_s/CIN
11.884 | 0.036 | tINS | RR | 1 | R45C56[0][A] | g_sound.u_seq_arb/cnt_next_12_s/COUT
11.884 | 0.000 | tNET | RR | 2 | R45C56[0][B] | g_sound.u_seq_arb/cnt_next_13_s/CIN
12.101 | 0.217 | tINS | RF | 1 | R45C56[0][B] | g_sound.u_seq_arb/cnt_next_13_s/SUM
12.264 | 0.163 | tNET | FF | 1 | R45C54[3][A] | g_sound.u_seq_arb/n2344_s5/I0
12.639 | 0.375 | tINS | FR | 1 | R45C54[3][A] | g_sound.u_seq_arb/n2344_s5/F
12.753 | 0.113 | tNET | RR | 1 | R45C53[0][A] | g_sound.u_seq_arb/n2344_s2/I2
13.124 | 0.372 | tINS | RR | 13 | R45C53[0][A] | g_sound.u_seq_arb/n2344_s2/F
13.975 | 0.850 | tNET | RR | 1 | R36C62[3][A] | g_sound.u_seq_arb/mem_s3115/I1
14.274 | 0.299 | tINS | RR | 2 | R36C62[3][A] | g_sound.u_seq_arb/mem_s3115/F
14.374 | 0.101 | tNET | RR | 1 | R36C62[3][B] | g_sound.u_seq_arb/mem_s3036/I3
14.733 | 0.358 | tINS | RR | 5 | R36C62[3][B] | g_sound.u_seq_arb/mem_s3036/F
15.310 | 0.578 | tNET | RR | 1 | R35C59[2][A] | g_sound.u_seq_arb/mem_s2747/I3
15.642 | 0.332 | tINS | RR | 43 | R35C59[2][A] | g_sound.u_seq_arb/mem_s2747/F
17.546 | 1.903 | tNET | RR | 1 | R44C55[3][A] | g_sound.u_seq_arb/mem_s2722/I0
17.921 | 0.375 | tINS | RR | 29 | R44C55[3][A] | g_sound.u_seq_arb/mem_s2722/F
18.906 | 0.985 | tNET | RR | 1 | R41C63[2][B] | g_sound.u_seq_arb/mem_mem_RAMREG_0_G[37]_s0/CE

Data Required Path:

AT | DELAY | TYPE | RF | FANOUT | LOC | NODE
20.000 | 20.000 | | | | | active clock edge time
20.000 | 0.000 | | | | | clk_sys
20.000 | 0.000 | tCL | RR | 1 | IOB117[B] | clk_ibuf/I
21.288 | 1.288 | tINS | RR | 15763 | IOB117[B] | clk_ibuf/O
23.571 | 2.283 | tNET | RR | 1 | R41C63[2][B] | g_sound.u_seq_arb/mem_mem_RAMREG_0_G[37]_s0/CLK
23.347 | -0.224 | tSu | | 1 | R41C63[2][B] | g_sound.u_seq_arb/mem_mem_RAMREG_0_G[37]_s0

Path Statistics:

Clock Skew | 0.000
Setup Relationship | 20.000
Logic Level | 17
Arrival Clock Path Delay | cell: 1.288, 36.076%; route: 2.283, 63.924%
Arrival Data Path Delay | cell: 5.197, 33.888%; route: 9.863, 64.316%; tC2Q: 0.275, 1.796%
Required Clock Path Delay | cell: 1.288, 36.076%; route: 2.283, 63.924%

### Path5

Path Summary:

Slack | 4.441
Data Arrival Time | 18.906
Data Required Time | 23.347
From | g_sound.u_seq_arb/cnt_q_0_s0
To | g_sound.u_seq_arb/mem_mem_RAMREG_0_G[35]_s0
Launch Clk | clk_sys:[R]
Latch Clk | clk_sys:[R]

Data Arrival Path:

AT | DELAY | TYPE | RF | FANOUT | LOC | NODE
0.000 | 0.000 | | | | | active clock edge time
0.000 | 0.000 | | | | | clk_sys
0.000 | 0.000 | tCL | RR | 1 | IOB117[B] | clk_ibuf/I
1.288 | 1.288 | tINS | RR | 15763 | IOB117[B] | clk_ibuf/O
3.571 | 2.283 | tNET | RR | 1 | R45C51[0][B] | g_sound.u_seq_arb/cnt_q_0_s0/CLK
3.847 | 0.275 | tC2Q | RR | 6 | R45C51[0][B] | g_sound.u_seq_arb/cnt_q_0_s0/Q
4.243 | 0.396 | tNET | RR | 1 | R46C53[0][A] | g_sound.u_seq_arb/cnt_after_pop_5_s1/I0
4.575 | 0.332 | tINS | RR | 5 | R46C53[0][A] | g_sound.u_seq_arb/cnt_after_pop_5_s1/F
4.889 | 0.314 | tNET | RR | 1 | R48C54[2][B] | g_sound.u_seq_arb/cnt_after_pop_8_s1/I3
5.078 | 0.189 | tINS | RR | 5 | R48C54[2][B] | g_sound.u_seq_arb/cnt_after_pop_8_s1/F
5.419 | 0.341 | tNET | RR | 1 | R46C53[3][B] | g_sound.u_seq_arb/cnt_after_pop_11_s1/I3
5.777 | 0.358 | tINS | RR | 5 | R46C53[3][B] | g_sound.u_seq_arb/cnt_after_pop_11_s1/F
6.130 | 0.353 | tNET | RR | 1 | R44C54[2][B] | g_sound.u_seq_arb/cnt_after_pop_13_s2/I3
6.462 | 0.332 | tINS | RR | 5 | R44C54[2][B] | g_sound.u_seq_arb/cnt_after_pop_13_s2/F
6.854 | 0.392 | tNET | RR | 1 | R45C52[1][A] | g_sound.u_seq_arb/pop_now_s2/I3
7.186 | 0.332 | tINS | RR | 82 | R45C52[1][A] | g_sound.u_seq_arb/pop_now_s2/F
10.110 | 2.924 | tNET | RR | 1 | R48C54[3][B] | g_sound.u_seq_arb/cnt_after_pop_6_s1/I3
10.485 | 0.375 | tINS | RR | 2 | R48C54[3][B] | g_sound.u_seq_arb/cnt_after_pop_6_s1/F
10.489 | 0.004 | tNET | RR | 1 | R48C54[1][B] | g_sound.u_seq_arb/cnt_after_pop_6_s0/I0
10.868 | 0.379 | tINS | RR | 1 | R48C54[1][B] | g_sound.u_seq_arb/cnt_after_pop_6_s0/F
11.313 | 0.446 | tNET | RR | 2 | R45C55[0][A] | g_sound.u_seq_arb/cnt_next_6_s/I1
11.668 | 0.355 | tINS | RR | 1 | R45C55[0][A] | g_sound.u_seq_arb/cnt_next_6_s/COUT
11.668 | 0.000 | tNET | RR | 2 | R45C55[0][B] | g_sound.u_seq_arb/cnt_next_7_s/CIN
11.704 | 0.036 | tINS | RR | 1 | R45C55[0][B] | g_sound.u_seq_arb/cnt_next_7_s/COUT
11.704 | 0.000 | tNET | RR | 2 | R45C55[1][A] | g_sound.u_seq_arb/cnt_next_8_s/CIN
11.740 | 0.036 | tINS | RR | 1 | R45C55[1][A] | g_sound.u_seq_arb/cnt_next_8_s/COUT
11.740 | 0.000 | tNET | RR | 2 | R45C55[1][B] | g_sound.u_seq_arb/cnt_next_9_s/CIN
11.776 | 0.036 | tINS | RR | 1 | R45C55[1][B] | g_sound.u_seq_arb/cnt_next_9_s/COUT
11.776 | 0.000 | tNET | RR | 2 | R45C55[2][A] | g_sound.u_seq_arb/cnt_next_10_s/CIN
11.812 | 0.036 | tINS | RR | 1 | R45C55[2][A] | g_sound.u_seq_arb/cnt_next_10_s/COUT
11.812 | 0.000 | tNET | RR | 2 | R45C55[2][B] | g_sound.u_seq_arb/cnt_next_11_s/CIN
11.848 | 0.036 | tINS | RR | 1 | R45C55[2][B] | g_sound.u_seq_arb/cnt_next_11_s/COUT
11.848 | 0.000 | tNET | RR | 2 | R45C56[0][A] | g_sound.u_seq_arb/cnt_next_12_s/CIN
11.884 | 0.036 | tINS | RR | 1 | R45C56[0][A] | g_sound.u_seq_arb/cnt_next_12_s/COUT
11.884 | 0.000 | tNET | RR | 2 | R45C56[0][B] | g_sound.u_seq_arb/cnt_next_13_s/CIN
12.101 | 0.217 | tINS | RF | 1 | R45C56[0][B] | g_sound.u_seq_arb/cnt_next_13_s/SUM
12.264 | 0.163 | tNET | FF | 1 | R45C54[3][A] | g_sound.u_seq_arb/n2344_s5/I0
12.639 | 0.375 | tINS | FR | 1 | R45C54[3][A] | g_sound.u_seq_arb/n2344_s5/F
12.753 | 0.113 | tNET | RR | 1 | R45C53[0][A] | g_sound.u_seq_arb/n2344_s2/I2
13.124 | 0.372 | tINS | RR | 13 | R45C53[0][A] | g_sound.u_seq_arb/n2344_s2/F
13.975 | 0.850 | tNET | RR | 1 | R36C62[3][A] | g_sound.u_seq_arb/mem_s3115/I1
14.274 | 0.299 | tINS | RR | 2 | R36C62[3][A] | g_sound.u_seq_arb/mem_s3115/F
14.374 | 0.101 | tNET | RR | 1 | R36C62[3][B] | g_sound.u_seq_arb/mem_s3036/I3
14.733 | 0.358 | tINS | RR | 5 | R36C62[3][B] | g_sound.u_seq_arb/mem_s3036/F
15.310 | 0.578 | tNET | RR | 1 | R35C59[2][A] | g_sound.u_seq_arb/mem_s2747/I3
15.642 | 0.332 | tINS | RR | 43 | R35C59[2][A] | g_sound.u_seq_arb/mem_s2747/F
17.546 | 1.903 | tNET | RR | 1 | R44C55[3][A] | g_sound.u_seq_arb/mem_s2722/I0
17.921 | 0.375 | tINS | RR | 29 | R44C55[3][A] | g_sound.u_seq_arb/mem_s2722/F
18.906 | 0.985 | tNET | RR | 1 | R41C63[1][A] | g_sound.u_seq_arb/mem_mem_RAMREG_0_G[35]_s0/CE

Data Required Path:

AT | DELAY | TYPE | RF | FANOUT | LOC | NODE
20.000 | 20.000 | | | | | active clock edge time
20.000 | 0.000 | | | | | clk_sys
20.000 | 0.000 | tCL | RR | 1 | IOB117[B] | clk_ibuf/I
21.288 | 1.288 | tINS | RR | 15763 | IOB117[B] | clk_ibuf/O
23.571 | 2.283 | tNET | RR | 1 | R41C63[1][A] | g_sound.u_seq_arb/mem_mem_RAMREG_0_G[35]_s0/CLK
23.347 | -0.224 | tSu | | 1 | R41C63[1][A] | g_sound.u_seq_arb/mem_mem_RAMREG_0_G[35]_s0

Path Statistics:

Clock Skew | 0.000
Setup Relationship | 20.000
Logic Level | 17
Arrival Clock Path Delay | cell: 1.288, 36.076%; route: 2.283, 63.924%
Arrival Data Path Delay | cell: 5.197, 33.888%; route: 9.863, 64.316%; tC2Q: 0.275, 1.796%
Required Clock Path Delay | cell: 1.288, 36.076%; route: 2.283, 63.924%

### Path6

Path Summary:

Slack | 4.441
Data Arrival Time | 18.906
Data Required Time | 23.347
From | g_sound.u_seq_arb/cnt_q_0_s0
To | g_sound.u_seq_arb/mem_mem_RAMREG_0_G[27]_s0
Launch Clk | clk_sys:[R]
Latch Clk | clk_sys:[R]

Data Arrival Path:

AT | DELAY | TYPE | RF | FANOUT | LOC | NODE
0.000 | 0.000 | | | | | active clock edge time
0.000 | 0.000 | | | | | clk_sys
0.000 | 0.000 | tCL | RR | 1 | IOB117[B] | clk_ibuf/I
1.288 | 1.288 | tINS | RR | 15763 | IOB117[B] | clk_ibuf/O
3.571 | 2.283 | tNET | RR | 1 | R45C51[0][B] | g_sound.u_seq_arb/cnt_q_0_s0/CLK
3.847 | 0.275 | tC2Q | RR | 6 | R45C51[0][B] | g_sound.u_seq_arb/cnt_q_0_s0/Q
4.243 | 0.396 | tNET | RR | 1 | R46C53[0][A] | g_sound.u_seq_arb/cnt_after_pop_5_s1/I0
4.575 | 0.332 | tINS | RR | 5 | R46C53[0][A] | g_sound.u_seq_arb/cnt_after_pop_5_s1/F
4.889 | 0.314 | tNET | RR | 1 | R48C54[2][B] | g_sound.u_seq_arb/cnt_after_pop_8_s1/I3
5.078 | 0.189 | tINS | RR | 5 | R48C54[2][B] | g_sound.u_seq_arb/cnt_after_pop_8_s1/F
5.419 | 0.341 | tNET | RR | 1 | R46C53[3][B] | g_sound.u_seq_arb/cnt_after_pop_11_s1/I3
5.777 | 0.358 | tINS | RR | 5 | R46C53[3][B] | g_sound.u_seq_arb/cnt_after_pop_11_s1/F
6.130 | 0.353 | tNET | RR | 1 | R44C54[2][B] | g_sound.u_seq_arb/cnt_after_pop_13_s2/I3
6.462 | 0.332 | tINS | RR | 5 | R44C54[2][B] | g_sound.u_seq_arb/cnt_after_pop_13_s2/F
6.854 | 0.392 | tNET | RR | 1 | R45C52[1][A] | g_sound.u_seq_arb/pop_now_s2/I3
7.186 | 0.332 | tINS | RR | 82 | R45C52[1][A] | g_sound.u_seq_arb/pop_now_s2/F
10.110 | 2.924 | tNET | RR | 1 | R48C54[3][B] | g_sound.u_seq_arb/cnt_after_pop_6_s1/I3
10.485 | 0.375 | tINS | RR | 2 | R48C54[3][B] | g_sound.u_seq_arb/cnt_after_pop_6_s1/F
10.489 | 0.004 | tNET | RR | 1 | R48C54[1][B] | g_sound.u_seq_arb/cnt_after_pop_6_s0/I0
10.868 | 0.379 | tINS | RR | 1 | R48C54[1][B] | g_sound.u_seq_arb/cnt_after_pop_6_s0/F
11.313 | 0.446 | tNET | RR | 2 | R45C55[0][A] | g_sound.u_seq_arb/cnt_next_6_s/I1
11.668 | 0.355 | tINS | RR | 1 | R45C55[0][A] | g_sound.u_seq_arb/cnt_next_6_s/COUT
11.668 | 0.000 | tNET | RR | 2 | R45C55[0][B] | g_sound.u_seq_arb/cnt_next_7_s/CIN
11.704 | 0.036 | tINS | RR | 1 | R45C55[0][B] | g_sound.u_seq_arb/cnt_next_7_s/COUT
11.704 | 0.000 | tNET | RR | 2 | R45C55[1][A] | g_sound.u_seq_arb/cnt_next_8_s/CIN
11.740 | 0.036 | tINS | RR | 1 | R45C55[1][A] | g_sound.u_seq_arb/cnt_next_8_s/COUT
11.740 | 0.000 | tNET | RR | 2 | R45C55[1][B] | g_sound.u_seq_arb/cnt_next_9_s/CIN
11.776 | 0.036 | tINS | RR | 1 | R45C55[1][B] | g_sound.u_seq_arb/cnt_next_9_s/COUT
11.776 | 0.000 | tNET | RR | 2 | R45C55[2][A] | g_sound.u_seq_arb/cnt_next_10_s/CIN
11.812 | 0.036 | tINS | RR | 1 | R45C55[2][A] | g_sound.u_seq_arb/cnt_next_10_s/COUT
11.812 | 0.000 | tNET | RR | 2 | R45C55[2][B] | g_sound.u_seq_arb/cnt_next_11_s/CIN
11.848 | 0.036 | tINS | RR | 1 | R45C55[2][B] | g_sound.u_seq_arb/cnt_next_11_s/COUT
11.848 | 0.000 | tNET | RR | 2 | R45C56[0][A] | g_sound.u_seq_arb/cnt_next_12_s/CIN
11.884 | 0.036 | tINS | RR | 1 | R45C56[0][A] | g_sound.u_seq_arb/cnt_next_12_s/COUT
11.884 | 0.000 | tNET | RR | 2 | R45C56[0][B] | g_sound.u_seq_arb/cnt_next_13_s/CIN
12.101 | 0.217 | tINS | RF | 1 | R45C56[0][B] | g_sound.u_seq_arb/cnt_next_13_s/SUM
12.264 | 0.163 | tNET | FF | 1 | R45C54[3][A] | g_sound.u_seq_arb/n2344_s5/I0
12.639 | 0.375 | tINS | FR | 1 | R45C54[3][A] | g_sound.u_seq_arb/n2344_s5/F
12.753 | 0.113 | tNET | RR | 1 | R45C53[0][A] | g_sound.u_seq_arb/n2344_s2/I2
13.124 | 0.372 | tINS | RR | 13 | R45C53[0][A] | g_sound.u_seq_arb/n2344_s2/F
13.975 | 0.850 | tNET | RR | 1 | R36C62[3][A] | g_sound.u_seq_arb/mem_s3115/I1
14.274 | 0.299 | tINS | RR | 2 | R36C62[3][A] | g_sound.u_seq_arb/mem_s3115/F
14.374 | 0.101 | tNET | RR | 1 | R36C62[3][B] | g_sound.u_seq_arb/mem_s3036/I3
14.733 | 0.358 | tINS | RR | 5 | R36C62[3][B] | g_sound.u_seq_arb/mem_s3036/F
15.310 | 0.578 | tNET | RR | 1 | R35C59[2][A] | g_sound.u_seq_arb/mem_s2747/I3
15.642 | 0.332 | tINS | RR | 43 | R35C59[2][A] | g_sound.u_seq_arb/mem_s2747/F
17.546 | 1.903 | tNET | RR | 1 | R44C55[3][A] | g_sound.u_seq_arb/mem_s2722/I0
17.921 | 0.375 | tINS | RR | 29 | R44C55[3][A] | g_sound.u_seq_arb/mem_s2722/F
18.906 | 0.985 | tNET | RR | 1 | R42C63[2][B] | g_sound.u_seq_arb/mem_mem_RAMREG_0_G[27]_s0/CE

Data Required Path:

AT | DELAY | TYPE | RF | FANOUT | LOC | NODE
20.000 | 20.000 | | | | | active clock edge time
20.000 | 0.000 | | | | | clk_sys
20.000 | 0.000 | tCL | RR | 1 | IOB117[B] | clk_ibuf/I
21.288 | 1.288 | tINS | RR | 15763 | IOB117[B] | clk_ibuf/O
23.571 | 2.283 | tNET | RR | 1 | R42C63[2][B] | g_sound.u_seq_arb/mem_mem_RAMREG_0_G[27]_s0/CLK
23.347 | -0.224 | tSu | | 1 | R42C63[2][B] | g_sound.u_seq_arb/mem_mem_RAMREG_0_G[27]_s0

Path Statistics:

Clock Skew | 0.000
Setup Relationship | 20.000
Logic Level | 17
Arrival Clock Path Delay | cell: 1.288, 36.076%; route: 2.283, 63.924%
Arrival Data Path Delay | cell: 5.197, 33.888%; route: 9.863, 64.316%; tC2Q: 0.275, 1.796%
Required Clock Path Delay | cell: 1.288, 36.076%; route: 2.283, 63.924%

### Path7

Path Summary:

Slack | 4.441
Data Arrival Time | 18.906
Data Required Time | 23.347
From | g_sound.u_seq_arb/cnt_q_0_s0
To | g_sound.u_seq_arb/mem_mem_RAMREG_0_G[25]_s0
Launch Clk | clk_sys:[R]
Latch Clk | clk_sys:[R]

Data Arrival Path:

AT | DELAY | TYPE | RF | FANOUT | LOC | NODE
0.000 | 0.000 | | | | | active clock edge time
0.000 | 0.000 | | | | | clk_sys
0.000 | 0.000 | tCL | RR | 1 | IOB117[B] | clk_ibuf/I
1.288 | 1.288 | tINS | RR | 15763 | IOB117[B] | clk_ibuf/O
3.571 | 2.283 | tNET | RR | 1 | R45C51[0][B] | g_sound.u_seq_arb/cnt_q_0_s0/CLK
3.847 | 0.275 | tC2Q | RR | 6 | R45C51[0][B] | g_sound.u_seq_arb/cnt_q_0_s0/Q
4.243 | 0.396 | tNET | RR | 1 | R46C53[0][A] | g_sound.u_seq_arb/cnt_after_pop_5_s1/I0
4.575 | 0.332 | tINS | RR | 5 | R46C53[0][A] | g_sound.u_seq_arb/cnt_after_pop_5_s1/F
4.889 | 0.314 | tNET | RR | 1 | R48C54[2][B] | g_sound.u_seq_arb/cnt_after_pop_8_s1/I3
5.078 | 0.189 | tINS | RR | 5 | R48C54[2][B] | g_sound.u_seq_arb/cnt_after_pop_8_s1/F
5.419 | 0.341 | tNET | RR | 1 | R46C53[3][B] | g_sound.u_seq_arb/cnt_after_pop_11_s1/I3
5.777 | 0.358 | tINS | RR | 5 | R46C53[3][B] | g_sound.u_seq_arb/cnt_after_pop_11_s1/F
6.130 | 0.353 | tNET | RR | 1 | R44C54[2][B] | g_sound.u_seq_arb/cnt_after_pop_13_s2/I3
6.462 | 0.332 | tINS | RR | 5 | R44C54[2][B] | g_sound.u_seq_arb/cnt_after_pop_13_s2/F
6.854 | 0.392 | tNET | RR | 1 | R45C52[1][A] | g_sound.u_seq_arb/pop_now_s2/I3
7.186 | 0.332 | tINS | RR | 82 | R45C52[1][A] | g_sound.u_seq_arb/pop_now_s2/F
10.110 | 2.924 | tNET | RR | 1 | R48C54[3][B] | g_sound.u_seq_arb/cnt_after_pop_6_s1/I3
10.485 | 0.375 | tINS | RR | 2 | R48C54[3][B] | g_sound.u_seq_arb/cnt_after_pop_6_s1/F
10.489 | 0.004 | tNET | RR | 1 | R48C54[1][B] | g_sound.u_seq_arb/cnt_after_pop_6_s0/I0
10.868 | 0.379 | tINS | RR | 1 | R48C54[1][B] | g_sound.u_seq_arb/cnt_after_pop_6_s0/F
11.313 | 0.446 | tNET | RR | 2 | R45C55[0][A] | g_sound.u_seq_arb/cnt_next_6_s/I1
11.668 | 0.355 | tINS | RR | 1 | R45C55[0][A] | g_sound.u_seq_arb/cnt_next_6_s/COUT
11.668 | 0.000 | tNET | RR | 2 | R45C55[0][B] | g_sound.u_seq_arb/cnt_next_7_s/CIN
11.704 | 0.036 | tINS | RR | 1 | R45C55[0][B] | g_sound.u_seq_arb/cnt_next_7_s/COUT
11.704 | 0.000 | tNET | RR | 2 | R45C55[1][A] | g_sound.u_seq_arb/cnt_next_8_s/CIN
11.740 | 0.036 | tINS | RR | 1 | R45C55[1][A] | g_sound.u_seq_arb/cnt_next_8_s/COUT
11.740 | 0.000 | tNET | RR | 2 | R45C55[1][B] | g_sound.u_seq_arb/cnt_next_9_s/CIN
11.776 | 0.036 | tINS | RR | 1 | R45C55[1][B] | g_sound.u_seq_arb/cnt_next_9_s/COUT
11.776 | 0.000 | tNET | RR | 2 | R45C55[2][A] | g_sound.u_seq_arb/cnt_next_10_s/CIN
11.812 | 0.036 | tINS | RR | 1 | R45C55[2][A] | g_sound.u_seq_arb/cnt_next_10_s/COUT
11.812 | 0.000 | tNET | RR | 2 | R45C55[2][B] | g_sound.u_seq_arb/cnt_next_11_s/CIN
11.848 | 0.036 | tINS | RR | 1 | R45C55[2][B] | g_sound.u_seq_arb/cnt_next_11_s/COUT
11.848 | 0.000 | tNET | RR | 2 | R45C56[0][A] | g_sound.u_seq_arb/cnt_next_12_s/CIN
11.884 | 0.036 | tINS | RR | 1 | R45C56[0][A] | g_sound.u_seq_arb/cnt_next_12_s/COUT
11.884 | 0.000 | tNET | RR | 2 | R45C56[0][B] | g_sound.u_seq_arb/cnt_next_13_s/CIN
12.101 | 0.217 | tINS | RF | 1 | R45C56[0][B] | g_sound.u_seq_arb/cnt_next_13_s/SUM
12.264 | 0.163 | tNET | FF | 1 | R45C54[3][A] | g_sound.u_seq_arb/n2344_s5/I0
12.639 | 0.375 | tINS | FR | 1 | R45C54[3][A] | g_sound.u_seq_arb/n2344_s5/F
12.753 | 0.113 | tNET | RR | 1 | R45C53[0][A] | g_sound.u_seq_arb/n2344_s2/I2
13.124 | 0.372 | tINS | RR | 13 | R45C53[0][A] | g_sound.u_seq_arb/n2344_s2/F
13.975 | 0.850 | tNET | RR | 1 | R36C62[3][A] | g_sound.u_seq_arb/mem_s3115/I1
14.274 | 0.299 | tINS | RR | 2 | R36C62[3][A] | g_sound.u_seq_arb/mem_s3115/F
14.374 | 0.101 | tNET | RR | 1 | R36C62[3][B] | g_sound.u_seq_arb/mem_s3036/I3
14.733 | 0.358 | tINS | RR | 5 | R36C62[3][B] | g_sound.u_seq_arb/mem_s3036/F
15.310 | 0.578 | tNET | RR | 1 | R35C59[2][A] | g_sound.u_seq_arb/mem_s2747/I3
15.642 | 0.332 | tINS | RR | 43 | R35C59[2][A] | g_sound.u_seq_arb/mem_s2747/F
17.546 | 1.903 | tNET | RR | 1 | R44C55[3][A] | g_sound.u_seq_arb/mem_s2722/I0
17.921 | 0.375 | tINS | RR | 29 | R44C55[3][A] | g_sound.u_seq_arb/mem_s2722/F
18.906 | 0.985 | tNET | RR | 1 | R42C63[2][A] | g_sound.u_seq_arb/mem_mem_RAMREG_0_G[25]_s0/CE

Data Required Path:

AT | DELAY | TYPE | RF | FANOUT | LOC | NODE
20.000 | 20.000 | | | | | active clock edge time
20.000 | 0.000 | | | | | clk_sys
20.000 | 0.000 | tCL | RR | 1 | IOB117[B] | clk_ibuf/I
21.288 | 1.288 | tINS | RR | 15763 | IOB117[B] | clk_ibuf/O
23.571 | 2.283 | tNET | RR | 1 | R42C63[2][A] | g_sound.u_seq_arb/mem_mem_RAMREG_0_G[25]_s0/CLK
23.347 | -0.224 | tSu | | 1 | R42C63[2][A] | g_sound.u_seq_arb/mem_mem_RAMREG_0_G[25]_s0

Path Statistics:

Clock Skew | 0.000
Setup Relationship | 20.000
Logic Level | 17
Arrival Clock Path Delay | cell: 1.288, 36.076%; route: 2.283, 63.924%
Arrival Data Path Delay | cell: 5.197, 33.888%; route: 9.863, 64.316%; tC2Q: 0.275, 1.796%
Required Clock Path Delay | cell: 1.288, 36.076%; route: 2.283, 63.924%

### Path8

Path Summary:

Slack | 4.473
Data Arrival Time | 18.868
Data Required Time | 23.340
From | g_sound.u_evt_merge/cnt_q_0_s0
To | g_sound.u_evt_merge/mem_mem_RAMREG_0_G[0]_s0
Launch Clk | clk_sys:[R]
Latch Clk | clk_sys:[R]

Data Arrival Path:

AT | DELAY | TYPE | RF | FANOUT | LOC | NODE
0.000 | 0.000 | | | | | active clock edge time
0.000 | 0.000 | | | | | clk_sys
0.000 | 0.000 | tCL | RR | 1 | IOB117[B] | clk_ibuf/I
1.288 | 1.288 | tINS | RR | 15763 | IOB117[B] | clk_ibuf/O
3.571 | 2.283 | tNET | RR | 1 | R61C51[1][B] | g_sound.u_evt_merge/cnt_q_0_s0/CLK
3.847 | 0.275 | tC2Q | RR | 6 | R61C51[1][B] | g_sound.u_evt_merge/cnt_q_0_s0/Q
3.967 | 0.121 | tNET | RR | 1 | R60C51[2][B] | g_sound.u_evt_merge/cnt_after_pop_5_s1/I0
4.346 | 0.379 | tINS | RR | 5 | R60C51[2][B] | g_sound.u_evt_merge/cnt_after_pop_5_s1/F
4.755 | 0.409 | tNET | RR | 1 | R60C47[2][B] | g_sound.u_evt_merge/cnt_after_pop_8_s1/I3
5.126 | 0.372 | tINS | RR | 5 | R60C47[2][B] | g_sound.u_evt_merge/cnt_after_pop_8_s1/F
5.132 | 0.005 | tNET | RR | 1 | R60C47[3][B] | g_sound.u_evt_merge/cnt_after_pop_11_s1/I3
5.490 | 0.358 | tINS | RR | 5 | R60C47[3][B] | g_sound.u_evt_merge/cnt_after_pop_11_s1/F
5.609 | 0.119 | tNET | RR | 1 | R59C47[0][A] | g_sound.u_evt_merge/cnt_after_pop_13_s2/I3
5.798 | 0.189 | tINS | RR | 5 | R59C47[0][A] | g_sound.u_evt_merge/cnt_after_pop_13_s2/F
5.944 | 0.146 | tNET | RR | 1 | R59C49[3][B] | g_sound.u_evt_merge/pop_now_s2/I3
6.134 | 0.191 | tINS | RR | 89 | R59C49[3][B] | g_sound.u_evt_merge/pop_now_s2/F
8.273 | 2.138 | tNET | RR | 1 | R60C51[2][A] | g_sound.u_evt_merge/cnt_after_pop_3_s1/I3
8.605 | 0.332 | tINS | RR | 2 | R60C51[2][A] | g_sound.u_evt_merge/cnt_after_pop_3_s1/F
8.720 | 0.115 | tNET | RR | 1 | R61C51[3][A] | g_sound.u_evt_merge/cnt_after_pop_3_s0/I0
8.911 | 0.191 | tINS | RR | 1 | R61C51[3][A] | g_sound.u_evt_merge/cnt_after_pop_3_s0/F
9.487 | 0.576 | tNET | RR | 2 | R61C45[1][B] | g_sound.u_evt_merge/cnt_next_3_s/I1
9.841 | 0.355 | tINS | RR | 1 | R61C45[1][B] | g_sound.u_evt_merge/cnt_next_3_s/COUT
9.841 | 0.000 | tNET | RR | 2 | R61C45[2][A] | g_sound.u_evt_merge/cnt_next_4_s/CIN
9.877 | 0.036 | tINS | RR | 1 | R61C45[2][A] | g_sound.u_evt_merge/cnt_next_4_s/COUT
9.877 | 0.000 | tNET | RR | 2 | R61C45[2][B] | g_sound.u_evt_merge/cnt_next_5_s/CIN
9.913 | 0.036 | tINS | RR | 1 | R61C45[2][B] | g_sound.u_evt_merge/cnt_next_5_s/COUT
9.913 | 0.000 | tNET | RR | 2 | R61C46[0][A] | g_sound.u_evt_merge/cnt_next_6_s/CIN
9.949 | 0.036 | tINS | RR | 1 | R61C46[0][A] | g_sound.u_evt_merge/cnt_next_6_s/COUT
9.949 | 0.000 | tNET | RR | 2 | R61C46[0][B] | g_sound.u_evt_merge/cnt_next_7_s/CIN
9.985 | 0.036 | tINS | RR | 1 | R61C46[0][B] | g_sound.u_evt_merge/cnt_next_7_s/COUT
9.985 | 0.000 | tNET | RR | 2 | R61C46[1][A] | g_sound.u_evt_merge/cnt_next_8_s/CIN
10.021 | 0.036 | tINS | RR | 1 | R61C46[1][A] | g_sound.u_evt_merge/cnt_next_8_s/COUT
10.021 | 0.000 | tNET | RR | 2 | R61C46[1][B] | g_sound.u_evt_merge/cnt_next_9_s/CIN
10.057 | 0.036 | tINS | RR | 1 | R61C46[1][B] | g_sound.u_evt_merge/cnt_next_9_s/COUT
10.057 | 0.000 | tNET | RR | 2 | R61C46[2][A] | g_sound.u_evt_merge/cnt_next_10_s/CIN
10.093 | 0.036 | tINS | RR | 1 | R61C46[2][A] | g_sound.u_evt_merge/cnt_next_10_s/COUT
10.093 | 0.000 | tNET | RR | 2 | R61C46[2][B] | g_sound.u_evt_merge/cnt_next_11_s/CIN
10.129 | 0.036 | tINS | RR | 1 | R61C46[2][B] | g_sound.u_evt_merge/cnt_next_11_s/COUT
10.129 | 0.000 | tNET | RR | 2 | R61C47[0][A] | g_sound.u_evt_merge/cnt_next_12_s/CIN
10.305 | 0.175 | tINS | RR | 1 | R61C47[0][A] | g_sound.u_evt_merge/cnt_next_12_s/SUM
10.573 | 0.268 | tNET | RR | 1 | R62C46[3][A] | g_sound.u_evt_merge/n1433_s3/I0
10.931 | 0.358 | tINS | RR | 1 | R62C46[3][A] | g_sound.u_evt_merge/n1433_s3/F
11.182 | 0.250 | tNET | RR | 1 | R61C45[3][A] | g_sound.u_evt_merge/n1433_s2/I2
11.557 | 0.375 | tINS | RR | 1 | R61C45[3][A] | g_sound.u_evt_merge/n1433_s2/F
11.825 | 0.268 | tNET | RR | 1 | R61C47[3][A] | g_sound.u_evt_merge/n1433_s1/I3
12.034 | 0.209 | tINS | RF | 1 | R61C47[3][A] | g_sound.u_evt_merge/n1433_s1/F
12.037 | 0.004 | tNET | FF | 1 | R61C47[2][B] | g_sound.u_evt_merge/n1433_s0/I3
12.370 | 0.332 | tINS | FR | 38 | R61C47[2][B] | g_sound.u_evt_merge/n1433_s0/F
13.089 | 0.719 | tNET | RR | 1 | R64C49[3][B] | g_sound.u_evt_merge/mem_s3593/I3
13.297 | 0.209 | tINS | RF | 1 | R64C49[3][B] | g_sound.u_evt_merge/mem_s3593/F
13.301 | 0.004 | tNET | FF | 1 | R64C49[0][B] | g_sound.u_evt_merge/mem_s3570/I2
13.680 | 0.379 | tINS | FR | 8 | R64C49[0][B] | g_sound.u_evt_merge/mem_s3570/F
14.230 | 0.550 | tNET | RR | 1 | R67C48[3][B] | g_sound.u_evt_merge/mem_s3512/I2
14.605 | 0.375 | tINS | RR | 70 | R67C48[3][B] | g_sound.u_evt_merge/mem_s3512/F
15.001 | 0.396 | tNET | RR | 1 | R66C47[2][B] | g_sound.u_evt_merge/mem_s3664/I3
15.380 | 0.379 | tINS | RR | 13 | R66C47[2][B] | g_sound.u_evt_merge/mem_s3664/F
16.357 | 0.976 | tNET | RR | 1 | R72C53[1][B] | g_sound.u_evt_merge/mem_s3073/I1
16.546 | 0.189 | tINS | RR | 50 | R72C53[1][B] | g_sound.u_evt_merge/mem_s3073/F
18.868 | 2.322 | tNET | RR | 1 | R51C46[3][B] | g_sound.u_evt_merge/mem_mem_RAMREG_0_G[0]_s0/CE

Data Required Path:

AT | DELAY | TYPE | RF | FANOUT | LOC | NODE
20.000 | 20.000 | | | | | active clock edge time
20.000 | 0.000 | | | | | clk_sys
20.000 | 0.000 | tCL | RR | 1 | IOB117[B] | clk_ibuf/I
21.288 | 1.288 | tINS | RR | 15763 | IOB117[B] | clk_ibuf/O
23.564 | 2.276 | tNET | RR | 1 | R51C46[3][B] | g_sound.u_evt_merge/mem_mem_RAMREG_0_G[0]_s0/CLK
23.340 | -0.224 | tSu | | 1 | R51C46[3][B] | g_sound.u_evt_merge/mem_mem_RAMREG_0_G[0]_s0

Path Statistics:

Clock Skew | -0.007
Setup Relationship | 20.000
Logic Level | 20
Arrival Clock Path Delay | cell: 1.288, 36.076%; route: 2.283, 63.924%
Arrival Data Path Delay | cell: 5.635, 36.838%; route: 9.386, 61.361%; tC2Q: 0.275, 1.800%
Required Clock Path Delay | cell: 1.288, 36.144%; route: 2.276, 63.856%

### Path9

Path Summary:

Slack | 4.473
Data Arrival Time | 18.868
Data Required Time | 23.340
From | g_sound.u_evt_merge/cnt_q_0_s0
To | g_sound.u_evt_merge/mem_mem_RAMREG_0_G[12]_s0
Launch Clk | clk_sys:[R]
Latch Clk | clk_sys:[R]

Data Arrival Path:

AT | DELAY | TYPE | RF | FANOUT | LOC | NODE
0.000 | 0.000 | | | | | active clock edge time
0.000 | 0.000 | | | | | clk_sys
0.000 | 0.000 | tCL | RR | 1 | IOB117[B] | clk_ibuf/I
1.288 | 1.288 | tINS | RR | 15763 | IOB117[B] | clk_ibuf/O
3.571 | 2.283 | tNET | RR | 1 | R61C51[1][B] | g_sound.u_evt_merge/cnt_q_0_s0/CLK
3.847 | 0.275 | tC2Q | RR | 6 | R61C51[1][B] | g_sound.u_evt_merge/cnt_q_0_s0/Q
3.967 | 0.121 | tNET | RR | 1 | R60C51[2][B] | g_sound.u_evt_merge/cnt_after_pop_5_s1/I0
4.346 | 0.379 | tINS | RR | 5 | R60C51[2][B] | g_sound.u_evt_merge/cnt_after_pop_5_s1/F
4.755 | 0.409 | tNET | RR | 1 | R60C47[2][B] | g_sound.u_evt_merge/cnt_after_pop_8_s1/I3
5.126 | 0.372 | tINS | RR | 5 | R60C47[2][B] | g_sound.u_evt_merge/cnt_after_pop_8_s1/F
5.132 | 0.005 | tNET | RR | 1 | R60C47[3][B] | g_sound.u_evt_merge/cnt_after_pop_11_s1/I3
5.490 | 0.358 | tINS | RR | 5 | R60C47[3][B] | g_sound.u_evt_merge/cnt_after_pop_11_s1/F
5.609 | 0.119 | tNET | RR | 1 | R59C47[0][A] | g_sound.u_evt_merge/cnt_after_pop_13_s2/I3
5.798 | 0.189 | tINS | RR | 5 | R59C47[0][A] | g_sound.u_evt_merge/cnt_after_pop_13_s2/F
5.944 | 0.146 | tNET | RR | 1 | R59C49[3][B] | g_sound.u_evt_merge/pop_now_s2/I3
6.134 | 0.191 | tINS | RR | 89 | R59C49[3][B] | g_sound.u_evt_merge/pop_now_s2/F
8.273 | 2.138 | tNET | RR | 1 | R60C51[2][A] | g_sound.u_evt_merge/cnt_after_pop_3_s1/I3
8.605 | 0.332 | tINS | RR | 2 | R60C51[2][A] | g_sound.u_evt_merge/cnt_after_pop_3_s1/F
8.720 | 0.115 | tNET | RR | 1 | R61C51[3][A] | g_sound.u_evt_merge/cnt_after_pop_3_s0/I0
8.911 | 0.191 | tINS | RR | 1 | R61C51[3][A] | g_sound.u_evt_merge/cnt_after_pop_3_s0/F
9.487 | 0.576 | tNET | RR | 2 | R61C45[1][B] | g_sound.u_evt_merge/cnt_next_3_s/I1
9.841 | 0.355 | tINS | RR | 1 | R61C45[1][B] | g_sound.u_evt_merge/cnt_next_3_s/COUT
9.841 | 0.000 | tNET | RR | 2 | R61C45[2][A] | g_sound.u_evt_merge/cnt_next_4_s/CIN
9.877 | 0.036 | tINS | RR | 1 | R61C45[2][A] | g_sound.u_evt_merge/cnt_next_4_s/COUT
9.877 | 0.000 | tNET | RR | 2 | R61C45[2][B] | g_sound.u_evt_merge/cnt_next_5_s/CIN
9.913 | 0.036 | tINS | RR | 1 | R61C45[2][B] | g_sound.u_evt_merge/cnt_next_5_s/COUT
9.913 | 0.000 | tNET | RR | 2 | R61C46[0][A] | g_sound.u_evt_merge/cnt_next_6_s/CIN
9.949 | 0.036 | tINS | RR | 1 | R61C46[0][A] | g_sound.u_evt_merge/cnt_next_6_s/COUT
9.949 | 0.000 | tNET | RR | 2 | R61C46[0][B] | g_sound.u_evt_merge/cnt_next_7_s/CIN
9.985 | 0.036 | tINS | RR | 1 | R61C46[0][B] | g_sound.u_evt_merge/cnt_next_7_s/COUT
9.985 | 0.000 | tNET | RR | 2 | R61C46[1][A] | g_sound.u_evt_merge/cnt_next_8_s/CIN
10.021 | 0.036 | tINS | RR | 1 | R61C46[1][A] | g_sound.u_evt_merge/cnt_next_8_s/COUT
10.021 | 0.000 | tNET | RR | 2 | R61C46[1][B] | g_sound.u_evt_merge/cnt_next_9_s/CIN
10.057 | 0.036 | tINS | RR | 1 | R61C46[1][B] | g_sound.u_evt_merge/cnt_next_9_s/COUT
10.057 | 0.000 | tNET | RR | 2 | R61C46[2][A] | g_sound.u_evt_merge/cnt_next_10_s/CIN
10.093 | 0.036 | tINS | RR | 1 | R61C46[2][A] | g_sound.u_evt_merge/cnt_next_10_s/COUT
10.093 | 0.000 | tNET | RR | 2 | R61C46[2][B] | g_sound.u_evt_merge/cnt_next_11_s/CIN
10.129 | 0.036 | tINS | RR | 1 | R61C46[2][B] | g_sound.u_evt_merge/cnt_next_11_s/COUT
10.129 | 0.000 | tNET | RR | 2 | R61C47[0][A] | g_sound.u_evt_merge/cnt_next_12_s/CIN
10.305 | 0.175 | tINS | RR | 1 | R61C47[0][A] | g_sound.u_evt_merge/cnt_next_12_s/SUM
10.573 | 0.268 | tNET | RR | 1 | R62C46[3][A] | g_sound.u_evt_merge/n1433_s3/I0
10.931 | 0.358 | tINS | RR | 1 | R62C46[3][A] | g_sound.u_evt_merge/n1433_s3/F
11.182 | 0.250 | tNET | RR | 1 | R61C45[3][A] | g_sound.u_evt_merge/n1433_s2/I2
11.557 | 0.375 | tINS | RR | 1 | R61C45[3][A] | g_sound.u_evt_merge/n1433_s2/F
11.825 | 0.268 | tNET | RR | 1 | R61C47[3][A] | g_sound.u_evt_merge/n1433_s1/I3
12.034 | 0.209 | tINS | RF | 1 | R61C47[3][A] | g_sound.u_evt_merge/n1433_s1/F
12.037 | 0.004 | tNET | FF | 1 | R61C47[2][B] | g_sound.u_evt_merge/n1433_s0/I3
12.370 | 0.332 | tINS | FR | 38 | R61C47[2][B] | g_sound.u_evt_merge/n1433_s0/F
13.089 | 0.719 | tNET | RR | 1 | R64C49[3][B] | g_sound.u_evt_merge/mem_s3593/I3
13.297 | 0.209 | tINS | RF | 1 | R64C49[3][B] | g_sound.u_evt_merge/mem_s3593/F
13.301 | 0.004 | tNET | FF | 1 | R64C49[0][B] | g_sound.u_evt_merge/mem_s3570/I2
13.680 | 0.379 | tINS | FR | 8 | R64C49[0][B] | g_sound.u_evt_merge/mem_s3570/F
14.230 | 0.550 | tNET | RR | 1 | R67C48[3][B] | g_sound.u_evt_merge/mem_s3512/I2
14.605 | 0.375 | tINS | RR | 70 | R67C48[3][B] | g_sound.u_evt_merge/mem_s3512/F
15.001 | 0.396 | tNET | RR | 1 | R66C47[2][B] | g_sound.u_evt_merge/mem_s3664/I3
15.380 | 0.379 | tINS | RR | 13 | R66C47[2][B] | g_sound.u_evt_merge/mem_s3664/F
16.357 | 0.976 | tNET | RR | 1 | R72C53[1][B] | g_sound.u_evt_merge/mem_s3073/I1
16.546 | 0.189 | tINS | RR | 50 | R72C53[1][B] | g_sound.u_evt_merge/mem_s3073/F
18.868 | 2.322 | tNET | RR | 1 | R51C46[1][A] | g_sound.u_evt_merge/mem_mem_RAMREG_0_G[12]_s0/CE

Data Required Path:

AT | DELAY | TYPE | RF | FANOUT | LOC | NODE
20.000 | 20.000 | | | | | active clock edge time
20.000 | 0.000 | | | | | clk_sys
20.000 | 0.000 | tCL | RR | 1 | IOB117[B] | clk_ibuf/I
21.288 | 1.288 | tINS | RR | 15763 | IOB117[B] | clk_ibuf/O
23.564 | 2.276 | tNET | RR | 1 | R51C46[1][A] | g_sound.u_evt_merge/mem_mem_RAMREG_0_G[12]_s0/CLK
23.340 | -0.224 | tSu | | 1 | R51C46[1][A] | g_sound.u_evt_merge/mem_mem_RAMREG_0_G[12]_s0

Path Statistics:

Clock Skew | -0.007
Setup Relationship | 20.000
Logic Level | 20
Arrival Clock Path Delay | cell: 1.288, 36.076%; route: 2.283, 63.924%
Arrival Data Path Delay | cell: 5.635, 36.838%; route: 9.386, 61.361%; tC2Q: 0.275, 1.800%
Required Clock Path Delay | cell: 1.288, 36.144%; route: 2.276, 63.856%

### Path10

Path Summary:

Slack | 4.488
Data Arrival Time | 18.859
Data Required Time | 23.347
From | g_sound.u_seq_arb/cnt_q_0_s0
To | g_sound.u_seq_arb/mem_mem_RAMREG_0_G[13]_s0
Launch Clk | clk_sys:[R]
Latch Clk | clk_sys:[R]

Data Arrival Path:

AT | DELAY | TYPE | RF | FANOUT | LOC | NODE
0.000 | 0.000 | | | | | active clock edge time
0.000 | 0.000 | | | | | clk_sys
0.000 | 0.000 | tCL | RR | 1 | IOB117[B] | clk_ibuf/I
1.288 | 1.288 | tINS | RR | 15763 | IOB117[B] | clk_ibuf/O
3.571 | 2.283 | tNET | RR | 1 | R45C51[0][B] | g_sound.u_seq_arb/cnt_q_0_s0/CLK
3.847 | 0.275 | tC2Q | RR | 6 | R45C51[0][B] | g_sound.u_seq_arb/cnt_q_0_s0/Q
4.243 | 0.396 | tNET | RR | 1 | R46C53[0][A] | g_sound.u_seq_arb/cnt_after_pop_5_s1/I0
4.575 | 0.332 | tINS | RR | 5 | R46C53[0][A] | g_sound.u_seq_arb/cnt_after_pop_5_s1/F
4.889 | 0.314 | tNET | RR | 1 | R48C54[2][B] | g_sound.u_seq_arb/cnt_after_pop_8_s1/I3
5.078 | 0.189 | tINS | RR | 5 | R48C54[2][B] | g_sound.u_seq_arb/cnt_after_pop_8_s1/F
5.419 | 0.341 | tNET | RR | 1 | R46C53[3][B] | g_sound.u_seq_arb/cnt_after_pop_11_s1/I3
5.777 | 0.358 | tINS | RR | 5 | R46C53[3][B] | g_sound.u_seq_arb/cnt_after_pop_11_s1/F
6.130 | 0.353 | tNET | RR | 1 | R44C54[2][B] | g_sound.u_seq_arb/cnt_after_pop_13_s2/I3
6.462 | 0.332 | tINS | RR | 5 | R44C54[2][B] | g_sound.u_seq_arb/cnt_after_pop_13_s2/F
6.854 | 0.392 | tNET | RR | 1 | R45C52[1][A] | g_sound.u_seq_arb/pop_now_s2/I3
7.186 | 0.332 | tINS | RR | 82 | R45C52[1][A] | g_sound.u_seq_arb/pop_now_s2/F
10.110 | 2.924 | tNET | RR | 1 | R48C54[3][B] | g_sound.u_seq_arb/cnt_after_pop_6_s1/I3
10.485 | 0.375 | tINS | RR | 2 | R48C54[3][B] | g_sound.u_seq_arb/cnt_after_pop_6_s1/F
10.489 | 0.004 | tNET | RR | 1 | R48C54[1][B] | g_sound.u_seq_arb/cnt_after_pop_6_s0/I0
10.868 | 0.379 | tINS | RR | 1 | R48C54[1][B] | g_sound.u_seq_arb/cnt_after_pop_6_s0/F
11.313 | 0.446 | tNET | RR | 2 | R45C55[0][A] | g_sound.u_seq_arb/cnt_next_6_s/I1
11.668 | 0.355 | tINS | RR | 1 | R45C55[0][A] | g_sound.u_seq_arb/cnt_next_6_s/COUT
11.668 | 0.000 | tNET | RR | 2 | R45C55[0][B] | g_sound.u_seq_arb/cnt_next_7_s/CIN
11.704 | 0.036 | tINS | RR | 1 | R45C55[0][B] | g_sound.u_seq_arb/cnt_next_7_s/COUT
11.704 | 0.000 | tNET | RR | 2 | R45C55[1][A] | g_sound.u_seq_arb/cnt_next_8_s/CIN
11.740 | 0.036 | tINS | RR | 1 | R45C55[1][A] | g_sound.u_seq_arb/cnt_next_8_s/COUT
11.740 | 0.000 | tNET | RR | 2 | R45C55[1][B] | g_sound.u_seq_arb/cnt_next_9_s/CIN
11.776 | 0.036 | tINS | RR | 1 | R45C55[1][B] | g_sound.u_seq_arb/cnt_next_9_s/COUT
11.776 | 0.000 | tNET | RR | 2 | R45C55[2][A] | g_sound.u_seq_arb/cnt_next_10_s/CIN
11.812 | 0.036 | tINS | RR | 1 | R45C55[2][A] | g_sound.u_seq_arb/cnt_next_10_s/COUT
11.812 | 0.000 | tNET | RR | 2 | R45C55[2][B] | g_sound.u_seq_arb/cnt_next_11_s/CIN
11.848 | 0.036 | tINS | RR | 1 | R45C55[2][B] | g_sound.u_seq_arb/cnt_next_11_s/COUT
11.848 | 0.000 | tNET | RR | 2 | R45C56[0][A] | g_sound.u_seq_arb/cnt_next_12_s/CIN
11.884 | 0.036 | tINS | RR | 1 | R45C56[0][A] | g_sound.u_seq_arb/cnt_next_12_s/COUT
11.884 | 0.000 | tNET | RR | 2 | R45C56[0][B] | g_sound.u_seq_arb/cnt_next_13_s/CIN
12.101 | 0.217 | tINS | RF | 1 | R45C56[0][B] | g_sound.u_seq_arb/cnt_next_13_s/SUM
12.264 | 0.163 | tNET | FF | 1 | R45C54[3][A] | g_sound.u_seq_arb/n2344_s5/I0
12.639 | 0.375 | tINS | FR | 1 | R45C54[3][A] | g_sound.u_seq_arb/n2344_s5/F
12.753 | 0.113 | tNET | RR | 1 | R45C53[0][A] | g_sound.u_seq_arb/n2344_s2/I2
13.124 | 0.372 | tINS | RR | 13 | R45C53[0][A] | g_sound.u_seq_arb/n2344_s2/F
13.975 | 0.850 | tNET | RR | 1 | R36C62[3][A] | g_sound.u_seq_arb/mem_s3115/I1
14.274 | 0.299 | tINS | RR | 2 | R36C62[3][A] | g_sound.u_seq_arb/mem_s3115/F
14.374 | 0.101 | tNET | RR | 1 | R36C62[3][B] | g_sound.u_seq_arb/mem_s3036/I3
14.733 | 0.358 | tINS | RR | 5 | R36C62[3][B] | g_sound.u_seq_arb/mem_s3036/F
15.310 | 0.578 | tNET | RR | 1 | R35C59[2][A] | g_sound.u_seq_arb/mem_s2747/I3
15.642 | 0.332 | tINS | RR | 43 | R35C59[2][A] | g_sound.u_seq_arb/mem_s2747/F
17.546 | 1.903 | tNET | RR | 1 | R44C55[3][A] | g_sound.u_seq_arb/mem_s2722/I0
17.921 | 0.375 | tINS | RR | 29 | R44C55[3][A] | g_sound.u_seq_arb/mem_s2722/F
18.859 | 0.938 | tNET | RR | 1 | R41C61[2][B] | g_sound.u_seq_arb/mem_mem_RAMREG_0_G[13]_s0/CE

Data Required Path:

AT | DELAY | TYPE | RF | FANOUT | LOC | NODE
20.000 | 20.000 | | | | | active clock edge time
20.000 | 0.000 | | | | | clk_sys
20.000 | 0.000 | tCL | RR | 1 | IOB117[B] | clk_ibuf/I
21.288 | 1.288 | tINS | RR | 15763 | IOB117[B] | clk_ibuf/O
23.571 | 2.283 | tNET | RR | 1 | R41C61[2][B] | g_sound.u_seq_arb/mem_mem_RAMREG_0_G[13]_s0/CLK
23.347 | -0.224 | tSu | | 1 | R41C61[2][B] | g_sound.u_seq_arb/mem_mem_RAMREG_0_G[13]_s0

Path Statistics:

Clock Skew | 0.000
Setup Relationship | 20.000
Logic Level | 17
Arrival Clock Path Delay | cell: 1.288, 36.076%; route: 2.283, 63.924%
Arrival Data Path Delay | cell: 5.197, 33.992%; route: 9.816, 64.207%; tC2Q: 0.275, 1.801%
Required Clock Path Delay | cell: 1.288, 36.076%; route: 2.283, 63.924%

### Path11

Path Summary:

Slack | 4.574
Data Arrival Time | 18.729
Data Required Time | 23.303
From | g_sound.u_seq_arb/cnt_q_0_s0
To | g_sound.u_seq_arb/mem_mem_RAMREG_4_G[48]_s0
Launch Clk | clk_sys:[R]
Latch Clk | clk_sys:[R]

Data Arrival Path:

AT | DELAY | TYPE | RF | FANOUT | LOC | NODE
0.000 | 0.000 | | | | | active clock edge time
0.000 | 0.000 | | | | | clk_sys
0.000 | 0.000 | tCL | RR | 1 | IOB117[B] | clk_ibuf/I
1.288 | 1.288 | tINS | RR | 15763 | IOB117[B] | clk_ibuf/O
3.571 | 2.283 | tNET | RR | 1 | R45C51[0][B] | g_sound.u_seq_arb/cnt_q_0_s0/CLK
3.847 | 0.275 | tC2Q | RR | 6 | R45C51[0][B] | g_sound.u_seq_arb/cnt_q_0_s0/Q
4.243 | 0.396 | tNET | RR | 1 | R46C53[0][A] | g_sound.u_seq_arb/cnt_after_pop_5_s1/I0
4.575 | 0.332 | tINS | RR | 5 | R46C53[0][A] | g_sound.u_seq_arb/cnt_after_pop_5_s1/F
4.889 | 0.314 | tNET | RR | 1 | R48C54[2][B] | g_sound.u_seq_arb/cnt_after_pop_8_s1/I3
5.078 | 0.189 | tINS | RR | 5 | R48C54[2][B] | g_sound.u_seq_arb/cnt_after_pop_8_s1/F
5.419 | 0.341 | tNET | RR | 1 | R46C53[3][B] | g_sound.u_seq_arb/cnt_after_pop_11_s1/I3
5.777 | 0.358 | tINS | RR | 5 | R46C53[3][B] | g_sound.u_seq_arb/cnt_after_pop_11_s1/F
6.130 | 0.353 | tNET | RR | 1 | R44C54[2][B] | g_sound.u_seq_arb/cnt_after_pop_13_s2/I3
6.462 | 0.332 | tINS | RR | 5 | R44C54[2][B] | g_sound.u_seq_arb/cnt_after_pop_13_s2/F
6.854 | 0.392 | tNET | RR | 1 | R45C52[1][A] | g_sound.u_seq_arb/pop_now_s2/I3
7.186 | 0.332 | tINS | RR | 82 | R45C52[1][A] | g_sound.u_seq_arb/pop_now_s2/F
10.110 | 2.924 | tNET | RR | 1 | R48C54[3][B] | g_sound.u_seq_arb/cnt_after_pop_6_s1/I3
10.485 | 0.375 | tINS | RR | 2 | R48C54[3][B] | g_sound.u_seq_arb/cnt_after_pop_6_s1/F
10.489 | 0.004 | tNET | RR | 1 | R48C54[1][B] | g_sound.u_seq_arb/cnt_after_pop_6_s0/I0
10.868 | 0.379 | tINS | RR | 1 | R48C54[1][B] | g_sound.u_seq_arb/cnt_after_pop_6_s0/F
11.313 | 0.446 | tNET | RR | 2 | R45C55[0][A] | g_sound.u_seq_arb/cnt_next_6_s/I1
11.668 | 0.355 | tINS | RR | 1 | R45C55[0][A] | g_sound.u_seq_arb/cnt_next_6_s/COUT
11.668 | 0.000 | tNET | RR | 2 | R45C55[0][B] | g_sound.u_seq_arb/cnt_next_7_s/CIN
11.704 | 0.036 | tINS | RR | 1 | R45C55[0][B] | g_sound.u_seq_arb/cnt_next_7_s/COUT
11.704 | 0.000 | tNET | RR | 2 | R45C55[1][A] | g_sound.u_seq_arb/cnt_next_8_s/CIN
11.740 | 0.036 | tINS | RR | 1 | R45C55[1][A] | g_sound.u_seq_arb/cnt_next_8_s/COUT
11.740 | 0.000 | tNET | RR | 2 | R45C55[1][B] | g_sound.u_seq_arb/cnt_next_9_s/CIN
11.776 | 0.036 | tINS | RR | 1 | R45C55[1][B] | g_sound.u_seq_arb/cnt_next_9_s/COUT
11.776 | 0.000 | tNET | RR | 2 | R45C55[2][A] | g_sound.u_seq_arb/cnt_next_10_s/CIN
11.812 | 0.036 | tINS | RR | 1 | R45C55[2][A] | g_sound.u_seq_arb/cnt_next_10_s/COUT
11.812 | 0.000 | tNET | RR | 2 | R45C55[2][B] | g_sound.u_seq_arb/cnt_next_11_s/CIN
11.848 | 0.036 | tINS | RR | 1 | R45C55[2][B] | g_sound.u_seq_arb/cnt_next_11_s/COUT
11.848 | 0.000 | tNET | RR | 2 | R45C56[0][A] | g_sound.u_seq_arb/cnt_next_12_s/CIN
11.884 | 0.036 | tINS | RR | 1 | R45C56[0][A] | g_sound.u_seq_arb/cnt_next_12_s/COUT
11.884 | 0.000 | tNET | RR | 2 | R45C56[0][B] | g_sound.u_seq_arb/cnt_next_13_s/CIN
12.101 | 0.217 | tINS | RF | 1 | R45C56[0][B] | g_sound.u_seq_arb/cnt_next_13_s/SUM
12.264 | 0.163 | tNET | FF | 1 | R45C54[3][A] | g_sound.u_seq_arb/n2344_s5/I0
12.639 | 0.375 | tINS | FR | 1 | R45C54[3][A] | g_sound.u_seq_arb/n2344_s5/F
12.753 | 0.113 | tNET | RR | 1 | R45C53[0][A] | g_sound.u_seq_arb/n2344_s2/I2
13.124 | 0.372 | tINS | RR | 13 | R45C53[0][A] | g_sound.u_seq_arb/n2344_s2/F
13.975 | 0.850 | tNET | RR | 1 | R36C62[3][A] | g_sound.u_seq_arb/mem_s3115/I1
14.274 | 0.299 | tINS | RR | 2 | R36C62[3][A] | g_sound.u_seq_arb/mem_s3115/F
14.374 | 0.101 | tNET | RR | 1 | R36C62[3][B] | g_sound.u_seq_arb/mem_s3036/I3
14.733 | 0.358 | tINS | RR | 5 | R36C62[3][B] | g_sound.u_seq_arb/mem_s3036/F
15.210 | 0.477 | tNET | RR | 1 | R35C59[1][B] | g_sound.u_seq_arb/mem_s3146/I3
15.542 | 0.332 | tINS | RR | 46 | R35C59[1][B] | g_sound.u_seq_arb/mem_s3146/F
17.826 | 2.284 | tNET | RR | 1 | R48C53[0][B] | g_sound.u_seq_arb/mem_mem_RAMREG_4_G[48]_s2/I2
18.205 | 0.379 | tINS | RR | 1 | R48C53[0][B] | g_sound.u_seq_arb/mem_mem_RAMREG_4_G[48]_s2/F
18.729 | 0.524 | tNET | RR | 1 | R48C53[0][A] | g_sound.u_seq_arb/mem_mem_RAMREG_4_G[48]_s0/RESET

Data Required Path:

AT | DELAY | TYPE | RF | FANOUT | LOC | NODE
20.000 | 20.000 | | | | | active clock edge time
20.000 | 0.000 | | | | | clk_sys
20.000 | 0.000 | tCL | RR | 1 | IOB117[B] | clk_ibuf/I
21.288 | 1.288 | tINS | RR | 15763 | IOB117[B] | clk_ibuf/O
23.571 | 2.283 | tNET | RR | 1 | R48C53[0][A] | g_sound.u_seq_arb/mem_mem_RAMREG_4_G[48]_s0/CLK
23.303 | -0.268 | tSu | | 1 | R48C53[0][A] | g_sound.u_seq_arb/mem_mem_RAMREG_4_G[48]_s0

Path Statistics:

Clock Skew | 0.000
Setup Relationship | 20.000
Logic Level | 17
Arrival Clock Path Delay | cell: 1.288, 36.076%; route: 2.283, 63.924%
Arrival Data Path Delay | cell: 5.200, 34.308%; route: 9.682, 63.875%; tC2Q: 0.275, 1.817%
Required Clock Path Delay | cell: 1.288, 36.076%; route: 2.283, 63.924%

### Path12

Path Summary:

Slack | 4.575
Data Arrival Time | 18.765
Data Required Time | 23.340
From | g_sound.u_seq_arb/cnt_q_0_s0
To | g_sound.u_seq_arb/mem_mem_RAMREG_0_G[46]_s0
Launch Clk | clk_sys:[R]
Latch Clk | clk_sys:[R]

Data Arrival Path:

AT | DELAY | TYPE | RF | FANOUT | LOC | NODE
0.000 | 0.000 | | | | | active clock edge time
0.000 | 0.000 | | | | | clk_sys
0.000 | 0.000 | tCL | RR | 1 | IOB117[B] | clk_ibuf/I
1.288 | 1.288 | tINS | RR | 15763 | IOB117[B] | clk_ibuf/O
3.571 | 2.283 | tNET | RR | 1 | R45C51[0][B] | g_sound.u_seq_arb/cnt_q_0_s0/CLK
3.847 | 0.275 | tC2Q | RR | 6 | R45C51[0][B] | g_sound.u_seq_arb/cnt_q_0_s0/Q
4.243 | 0.396 | tNET | RR | 1 | R46C53[0][A] | g_sound.u_seq_arb/cnt_after_pop_5_s1/I0
4.575 | 0.332 | tINS | RR | 5 | R46C53[0][A] | g_sound.u_seq_arb/cnt_after_pop_5_s1/F
4.889 | 0.314 | tNET | RR | 1 | R48C54[2][B] | g_sound.u_seq_arb/cnt_after_pop_8_s1/I3
5.078 | 0.189 | tINS | RR | 5 | R48C54[2][B] | g_sound.u_seq_arb/cnt_after_pop_8_s1/F
5.419 | 0.341 | tNET | RR | 1 | R46C53[3][B] | g_sound.u_seq_arb/cnt_after_pop_11_s1/I3
5.777 | 0.358 | tINS | RR | 5 | R46C53[3][B] | g_sound.u_seq_arb/cnt_after_pop_11_s1/F
6.130 | 0.353 | tNET | RR | 1 | R44C54[2][B] | g_sound.u_seq_arb/cnt_after_pop_13_s2/I3
6.462 | 0.332 | tINS | RR | 5 | R44C54[2][B] | g_sound.u_seq_arb/cnt_after_pop_13_s2/F
6.854 | 0.392 | tNET | RR | 1 | R45C52[1][A] | g_sound.u_seq_arb/pop_now_s2/I3
7.186 | 0.332 | tINS | RR | 82 | R45C52[1][A] | g_sound.u_seq_arb/pop_now_s2/F
10.110 | 2.924 | tNET | RR | 1 | R48C54[3][B] | g_sound.u_seq_arb/cnt_after_pop_6_s1/I3
10.485 | 0.375 | tINS | RR | 2 | R48C54[3][B] | g_sound.u_seq_arb/cnt_after_pop_6_s1/F
10.489 | 0.004 | tNET | RR | 1 | R48C54[1][B] | g_sound.u_seq_arb/cnt_after_pop_6_s0/I0
10.868 | 0.379 | tINS | RR | 1 | R48C54[1][B] | g_sound.u_seq_arb/cnt_after_pop_6_s0/F
11.313 | 0.446 | tNET | RR | 2 | R45C55[0][A] | g_sound.u_seq_arb/cnt_next_6_s/I1
11.668 | 0.355 | tINS | RR | 1 | R45C55[0][A] | g_sound.u_seq_arb/cnt_next_6_s/COUT
11.668 | 0.000 | tNET | RR | 2 | R45C55[0][B] | g_sound.u_seq_arb/cnt_next_7_s/CIN
11.704 | 0.036 | tINS | RR | 1 | R45C55[0][B] | g_sound.u_seq_arb/cnt_next_7_s/COUT
11.704 | 0.000 | tNET | RR | 2 | R45C55[1][A] | g_sound.u_seq_arb/cnt_next_8_s/CIN
11.740 | 0.036 | tINS | RR | 1 | R45C55[1][A] | g_sound.u_seq_arb/cnt_next_8_s/COUT
11.740 | 0.000 | tNET | RR | 2 | R45C55[1][B] | g_sound.u_seq_arb/cnt_next_9_s/CIN
11.776 | 0.036 | tINS | RR | 1 | R45C55[1][B] | g_sound.u_seq_arb/cnt_next_9_s/COUT
11.776 | 0.000 | tNET | RR | 2 | R45C55[2][A] | g_sound.u_seq_arb/cnt_next_10_s/CIN
11.812 | 0.036 | tINS | RR | 1 | R45C55[2][A] | g_sound.u_seq_arb/cnt_next_10_s/COUT
11.812 | 0.000 | tNET | RR | 2 | R45C55[2][B] | g_sound.u_seq_arb/cnt_next_11_s/CIN
11.848 | 0.036 | tINS | RR | 1 | R45C55[2][B] | g_sound.u_seq_arb/cnt_next_11_s/COUT
11.848 | 0.000 | tNET | RR | 2 | R45C56[0][A] | g_sound.u_seq_arb/cnt_next_12_s/CIN
11.884 | 0.036 | tINS | RR | 1 | R45C56[0][A] | g_sound.u_seq_arb/cnt_next_12_s/COUT
11.884 | 0.000 | tNET | RR | 2 | R45C56[0][B] | g_sound.u_seq_arb/cnt_next_13_s/CIN
12.101 | 0.217 | tINS | RF | 1 | R45C56[0][B] | g_sound.u_seq_arb/cnt_next_13_s/SUM
12.264 | 0.163 | tNET | FF | 1 | R45C54[3][A] | g_sound.u_seq_arb/n2344_s5/I0
12.639 | 0.375 | tINS | FR | 1 | R45C54[3][A] | g_sound.u_seq_arb/n2344_s5/F
12.753 | 0.113 | tNET | RR | 1 | R45C53[0][A] | g_sound.u_seq_arb/n2344_s2/I2
13.124 | 0.372 | tINS | RR | 13 | R45C53[0][A] | g_sound.u_seq_arb/n2344_s2/F
13.975 | 0.850 | tNET | RR | 1 | R36C62[3][A] | g_sound.u_seq_arb/mem_s3115/I1
14.274 | 0.299 | tINS | RR | 2 | R36C62[3][A] | g_sound.u_seq_arb/mem_s3115/F
14.374 | 0.101 | tNET | RR | 1 | R36C62[3][B] | g_sound.u_seq_arb/mem_s3036/I3
14.733 | 0.358 | tINS | RR | 5 | R36C62[3][B] | g_sound.u_seq_arb/mem_s3036/F
15.310 | 0.578 | tNET | RR | 1 | R35C59[2][A] | g_sound.u_seq_arb/mem_s2747/I3
15.642 | 0.332 | tINS | RR | 43 | R35C59[2][A] | g_sound.u_seq_arb/mem_s2747/F
17.546 | 1.903 | tNET | RR | 1 | R44C55[3][A] | g_sound.u_seq_arb/mem_s2722/I0
17.921 | 0.375 | tINS | RR | 29 | R44C55[3][A] | g_sound.u_seq_arb/mem_s2722/F
18.765 | 0.844 | tNET | RR | 1 | R43C62[0][B] | g_sound.u_seq_arb/mem_mem_RAMREG_0_G[46]_s0/CE

Data Required Path:

AT | DELAY | TYPE | RF | FANOUT | LOC | NODE
20.000 | 20.000 | | | | | active clock edge time
20.000 | 0.000 | | | | | clk_sys
20.000 | 0.000 | tCL | RR | 1 | IOB117[B] | clk_ibuf/I
21.288 | 1.288 | tINS | RR | 15763 | IOB117[B] | clk_ibuf/O
23.564 | 2.276 | tNET | RR | 1 | R43C62[0][B] | g_sound.u_seq_arb/mem_mem_RAMREG_0_G[46]_s0/CLK
23.340 | -0.224 | tSu | | 1 | R43C62[0][B] | g_sound.u_seq_arb/mem_mem_RAMREG_0_G[46]_s0

Path Statistics:

Clock Skew | -0.007
Setup Relationship | 20.000
Logic Level | 17
Arrival Clock Path Delay | cell: 1.288, 36.076%; route: 2.283, 63.924%
Arrival Data Path Delay | cell: 5.197, 34.201%; route: 9.722, 63.986%; tC2Q: 0.275, 1.813%
Required Clock Path Delay | cell: 1.288, 36.144%; route: 2.276, 63.856%

### Path13

Path Summary:

Slack | 4.575
Data Arrival Time | 18.765
Data Required Time | 23.340
From | g_sound.u_seq_arb/cnt_q_0_s0
To | g_sound.u_seq_arb/mem_mem_RAMREG_0_G[45]_s0
Launch Clk | clk_sys:[R]
Latch Clk | clk_sys:[R]

Data Arrival Path:

AT | DELAY | TYPE | RF | FANOUT | LOC | NODE
0.000 | 0.000 | | | | | active clock edge time
0.000 | 0.000 | | | | | clk_sys
0.000 | 0.000 | tCL | RR | 1 | IOB117[B] | clk_ibuf/I
1.288 | 1.288 | tINS | RR | 15763 | IOB117[B] | clk_ibuf/O
3.571 | 2.283 | tNET | RR | 1 | R45C51[0][B] | g_sound.u_seq_arb/cnt_q_0_s0/CLK
3.847 | 0.275 | tC2Q | RR | 6 | R45C51[0][B] | g_sound.u_seq_arb/cnt_q_0_s0/Q
4.243 | 0.396 | tNET | RR | 1 | R46C53[0][A] | g_sound.u_seq_arb/cnt_after_pop_5_s1/I0
4.575 | 0.332 | tINS | RR | 5 | R46C53[0][A] | g_sound.u_seq_arb/cnt_after_pop_5_s1/F
4.889 | 0.314 | tNET | RR | 1 | R48C54[2][B] | g_sound.u_seq_arb/cnt_after_pop_8_s1/I3
5.078 | 0.189 | tINS | RR | 5 | R48C54[2][B] | g_sound.u_seq_arb/cnt_after_pop_8_s1/F
5.419 | 0.341 | tNET | RR | 1 | R46C53[3][B] | g_sound.u_seq_arb/cnt_after_pop_11_s1/I3
5.777 | 0.358 | tINS | RR | 5 | R46C53[3][B] | g_sound.u_seq_arb/cnt_after_pop_11_s1/F
6.130 | 0.353 | tNET | RR | 1 | R44C54[2][B] | g_sound.u_seq_arb/cnt_after_pop_13_s2/I3
6.462 | 0.332 | tINS | RR | 5 | R44C54[2][B] | g_sound.u_seq_arb/cnt_after_pop_13_s2/F
6.854 | 0.392 | tNET | RR | 1 | R45C52[1][A] | g_sound.u_seq_arb/pop_now_s2/I3
7.186 | 0.332 | tINS | RR | 82 | R45C52[1][A] | g_sound.u_seq_arb/pop_now_s2/F
10.110 | 2.924 | tNET | RR | 1 | R48C54[3][B] | g_sound.u_seq_arb/cnt_after_pop_6_s1/I3
10.485 | 0.375 | tINS | RR | 2 | R48C54[3][B] | g_sound.u_seq_arb/cnt_after_pop_6_s1/F
10.489 | 0.004 | tNET | RR | 1 | R48C54[1][B] | g_sound.u_seq_arb/cnt_after_pop_6_s0/I0
10.868 | 0.379 | tINS | RR | 1 | R48C54[1][B] | g_sound.u_seq_arb/cnt_after_pop_6_s0/F
11.313 | 0.446 | tNET | RR | 2 | R45C55[0][A] | g_sound.u_seq_arb/cnt_next_6_s/I1
11.668 | 0.355 | tINS | RR | 1 | R45C55[0][A] | g_sound.u_seq_arb/cnt_next_6_s/COUT
11.668 | 0.000 | tNET | RR | 2 | R45C55[0][B] | g_sound.u_seq_arb/cnt_next_7_s/CIN
11.704 | 0.036 | tINS | RR | 1 | R45C55[0][B] | g_sound.u_seq_arb/cnt_next_7_s/COUT
11.704 | 0.000 | tNET | RR | 2 | R45C55[1][A] | g_sound.u_seq_arb/cnt_next_8_s/CIN
11.740 | 0.036 | tINS | RR | 1 | R45C55[1][A] | g_sound.u_seq_arb/cnt_next_8_s/COUT
11.740 | 0.000 | tNET | RR | 2 | R45C55[1][B] | g_sound.u_seq_arb/cnt_next_9_s/CIN
11.776 | 0.036 | tINS | RR | 1 | R45C55[1][B] | g_sound.u_seq_arb/cnt_next_9_s/COUT
11.776 | 0.000 | tNET | RR | 2 | R45C55[2][A] | g_sound.u_seq_arb/cnt_next_10_s/CIN
11.812 | 0.036 | tINS | RR | 1 | R45C55[2][A] | g_sound.u_seq_arb/cnt_next_10_s/COUT
11.812 | 0.000 | tNET | RR | 2 | R45C55[2][B] | g_sound.u_seq_arb/cnt_next_11_s/CIN
11.848 | 0.036 | tINS | RR | 1 | R45C55[2][B] | g_sound.u_seq_arb/cnt_next_11_s/COUT
11.848 | 0.000 | tNET | RR | 2 | R45C56[0][A] | g_sound.u_seq_arb/cnt_next_12_s/CIN
11.884 | 0.036 | tINS | RR | 1 | R45C56[0][A] | g_sound.u_seq_arb/cnt_next_12_s/COUT
11.884 | 0.000 | tNET | RR | 2 | R45C56[0][B] | g_sound.u_seq_arb/cnt_next_13_s/CIN
12.101 | 0.217 | tINS | RF | 1 | R45C56[0][B] | g_sound.u_seq_arb/cnt_next_13_s/SUM
12.264 | 0.163 | tNET | FF | 1 | R45C54[3][A] | g_sound.u_seq_arb/n2344_s5/I0
12.639 | 0.375 | tINS | FR | 1 | R45C54[3][A] | g_sound.u_seq_arb/n2344_s5/F
12.753 | 0.113 | tNET | RR | 1 | R45C53[0][A] | g_sound.u_seq_arb/n2344_s2/I2
13.124 | 0.372 | tINS | RR | 13 | R45C53[0][A] | g_sound.u_seq_arb/n2344_s2/F
13.975 | 0.850 | tNET | RR | 1 | R36C62[3][A] | g_sound.u_seq_arb/mem_s3115/I1
14.274 | 0.299 | tINS | RR | 2 | R36C62[3][A] | g_sound.u_seq_arb/mem_s3115/F
14.374 | 0.101 | tNET | RR | 1 | R36C62[3][B] | g_sound.u_seq_arb/mem_s3036/I3
14.733 | 0.358 | tINS | RR | 5 | R36C62[3][B] | g_sound.u_seq_arb/mem_s3036/F
15.310 | 0.578 | tNET | RR | 1 | R35C59[2][A] | g_sound.u_seq_arb/mem_s2747/I3
15.642 | 0.332 | tINS | RR | 43 | R35C59[2][A] | g_sound.u_seq_arb/mem_s2747/F
17.546 | 1.903 | tNET | RR | 1 | R44C55[3][A] | g_sound.u_seq_arb/mem_s2722/I0
17.921 | 0.375 | tINS | RR | 29 | R44C55[3][A] | g_sound.u_seq_arb/mem_s2722/F
18.765 | 0.844 | tNET | RR | 1 | R43C62[2][B] | g_sound.u_seq_arb/mem_mem_RAMREG_0_G[45]_s0/CE

Data Required Path:

AT | DELAY | TYPE | RF | FANOUT | LOC | NODE
20.000 | 20.000 | | | | | active clock edge time
20.000 | 0.000 | | | | | clk_sys
20.000 | 0.000 | tCL | RR | 1 | IOB117[B] | clk_ibuf/I
21.288 | 1.288 | tINS | RR | 15763 | IOB117[B] | clk_ibuf/O
23.564 | 2.276 | tNET | RR | 1 | R43C62[2][B] | g_sound.u_seq_arb/mem_mem_RAMREG_0_G[45]_s0/CLK
23.340 | -0.224 | tSu | | 1 | R43C62[2][B] | g_sound.u_seq_arb/mem_mem_RAMREG_0_G[45]_s0

Path Statistics:

Clock Skew | -0.007
Setup Relationship | 20.000
Logic Level | 17
Arrival Clock Path Delay | cell: 1.288, 36.076%; route: 2.283, 63.924%
Arrival Data Path Delay | cell: 5.197, 34.201%; route: 9.722, 63.986%; tC2Q: 0.275, 1.813%
Required Clock Path Delay | cell: 1.288, 36.144%; route: 2.276, 63.856%

### Path14

Path Summary:

Slack | 4.671
Data Arrival Time | 18.625
Data Required Time | 23.296
From | g_sound.u_seq_arb/cnt_q_0_s0
To | g_sound.u_seq_arb/mem_mem_RAMREG_4_G[1]_s0
Launch Clk | clk_sys:[R]
Latch Clk | clk_sys:[R]

Data Arrival Path:

AT | DELAY | TYPE | RF | FANOUT | LOC | NODE
0.000 | 0.000 | | | | | active clock edge time
0.000 | 0.000 | | | | | clk_sys
0.000 | 0.000 | tCL | RR | 1 | IOB117[B] | clk_ibuf/I
1.288 | 1.288 | tINS | RR | 15763 | IOB117[B] | clk_ibuf/O
3.571 | 2.283 | tNET | RR | 1 | R45C51[0][B] | g_sound.u_seq_arb/cnt_q_0_s0/CLK
3.847 | 0.275 | tC2Q | RR | 6 | R45C51[0][B] | g_sound.u_seq_arb/cnt_q_0_s0/Q
4.243 | 0.396 | tNET | RR | 1 | R46C53[0][A] | g_sound.u_seq_arb/cnt_after_pop_5_s1/I0
4.575 | 0.332 | tINS | RR | 5 | R46C53[0][A] | g_sound.u_seq_arb/cnt_after_pop_5_s1/F
4.889 | 0.314 | tNET | RR | 1 | R48C54[2][B] | g_sound.u_seq_arb/cnt_after_pop_8_s1/I3
5.078 | 0.189 | tINS | RR | 5 | R48C54[2][B] | g_sound.u_seq_arb/cnt_after_pop_8_s1/F
5.419 | 0.341 | tNET | RR | 1 | R46C53[3][B] | g_sound.u_seq_arb/cnt_after_pop_11_s1/I3
5.777 | 0.358 | tINS | RR | 5 | R46C53[3][B] | g_sound.u_seq_arb/cnt_after_pop_11_s1/F
6.130 | 0.353 | tNET | RR | 1 | R44C54[2][B] | g_sound.u_seq_arb/cnt_after_pop_13_s2/I3
6.462 | 0.332 | tINS | RR | 5 | R44C54[2][B] | g_sound.u_seq_arb/cnt_after_pop_13_s2/F
6.854 | 0.392 | tNET | RR | 1 | R45C52[1][A] | g_sound.u_seq_arb/pop_now_s2/I3
7.186 | 0.332 | tINS | RR | 82 | R45C52[1][A] | g_sound.u_seq_arb/pop_now_s2/F
10.110 | 2.924 | tNET | RR | 1 | R48C54[3][B] | g_sound.u_seq_arb/cnt_after_pop_6_s1/I3
10.485 | 0.375 | tINS | RR | 2 | R48C54[3][B] | g_sound.u_seq_arb/cnt_after_pop_6_s1/F
10.489 | 0.004 | tNET | RR | 1 | R48C54[1][B] | g_sound.u_seq_arb/cnt_after_pop_6_s0/I0
10.868 | 0.379 | tINS | RR | 1 | R48C54[1][B] | g_sound.u_seq_arb/cnt_after_pop_6_s0/F
11.313 | 0.446 | tNET | RR | 2 | R45C55[0][A] | g_sound.u_seq_arb/cnt_next_6_s/I1
11.668 | 0.355 | tINS | RR | 1 | R45C55[0][A] | g_sound.u_seq_arb/cnt_next_6_s/COUT
11.668 | 0.000 | tNET | RR | 2 | R45C55[0][B] | g_sound.u_seq_arb/cnt_next_7_s/CIN
11.704 | 0.036 | tINS | RR | 1 | R45C55[0][B] | g_sound.u_seq_arb/cnt_next_7_s/COUT
11.704 | 0.000 | tNET | RR | 2 | R45C55[1][A] | g_sound.u_seq_arb/cnt_next_8_s/CIN
11.740 | 0.036 | tINS | RR | 1 | R45C55[1][A] | g_sound.u_seq_arb/cnt_next_8_s/COUT
11.740 | 0.000 | tNET | RR | 2 | R45C55[1][B] | g_sound.u_seq_arb/cnt_next_9_s/CIN
11.776 | 0.036 | tINS | RR | 1 | R45C55[1][B] | g_sound.u_seq_arb/cnt_next_9_s/COUT
11.776 | 0.000 | tNET | RR | 2 | R45C55[2][A] | g_sound.u_seq_arb/cnt_next_10_s/CIN
11.812 | 0.036 | tINS | RR | 1 | R45C55[2][A] | g_sound.u_seq_arb/cnt_next_10_s/COUT
11.812 | 0.000 | tNET | RR | 2 | R45C55[2][B] | g_sound.u_seq_arb/cnt_next_11_s/CIN
11.848 | 0.036 | tINS | RR | 1 | R45C55[2][B] | g_sound.u_seq_arb/cnt_next_11_s/COUT
11.848 | 0.000 | tNET | RR | 2 | R45C56[0][A] | g_sound.u_seq_arb/cnt_next_12_s/CIN
11.884 | 0.036 | tINS | RR | 1 | R45C56[0][A] | g_sound.u_seq_arb/cnt_next_12_s/COUT
11.884 | 0.000 | tNET | RR | 2 | R45C56[0][B] | g_sound.u_seq_arb/cnt_next_13_s/CIN
12.101 | 0.217 | tINS | RF | 1 | R45C56[0][B] | g_sound.u_seq_arb/cnt_next_13_s/SUM
12.264 | 0.163 | tNET | FF | 1 | R45C54[3][A] | g_sound.u_seq_arb/n2344_s5/I0
12.639 | 0.375 | tINS | FR | 1 | R45C54[3][A] | g_sound.u_seq_arb/n2344_s5/F
12.753 | 0.113 | tNET | RR | 1 | R45C53[0][A] | g_sound.u_seq_arb/n2344_s2/I2
13.124 | 0.372 | tINS | RR | 13 | R45C53[0][A] | g_sound.u_seq_arb/n2344_s2/F
13.975 | 0.850 | tNET | RR | 1 | R36C62[3][A] | g_sound.u_seq_arb/mem_s3115/I1
14.274 | 0.299 | tINS | RR | 2 | R36C62[3][A] | g_sound.u_seq_arb/mem_s3115/F
14.374 | 0.101 | tNET | RR | 1 | R36C62[3][B] | g_sound.u_seq_arb/mem_s3036/I3
14.733 | 0.358 | tINS | RR | 5 | R36C62[3][B] | g_sound.u_seq_arb/mem_s3036/F
15.210 | 0.477 | tNET | RR | 1 | R35C59[1][B] | g_sound.u_seq_arb/mem_s3146/I3
15.542 | 0.332 | tINS | RR | 46 | R35C59[1][B] | g_sound.u_seq_arb/mem_s3146/F
17.769 | 2.228 | tNET | RR | 1 | R46C54[1][B] | g_sound.u_seq_arb/mem_mem_RAMREG_4_G[1]_s2/I2
18.101 | 0.332 | tINS | RR | 1 | R46C54[1][B] | g_sound.u_seq_arb/mem_mem_RAMREG_4_G[1]_s2/F
18.625 | 0.524 | tNET | RR | 1 | R46C54[0][A] | g_sound.u_seq_arb/mem_mem_RAMREG_4_G[1]_s0/RESET

Data Required Path:

AT | DELAY | TYPE | RF | FANOUT | LOC | NODE
20.000 | 20.000 | | | | | active clock edge time
20.000 | 0.000 | | | | | clk_sys
20.000 | 0.000 | tCL | RR | 1 | IOB117[B] | clk_ibuf/I
21.288 | 1.288 | tINS | RR | 15763 | IOB117[B] | clk_ibuf/O
23.564 | 2.276 | tNET | RR | 1 | R46C54[0][A] | g_sound.u_seq_arb/mem_mem_RAMREG_4_G[1]_s0/CLK
23.296 | -0.268 | tSu | | 1 | R46C54[0][A] | g_sound.u_seq_arb/mem_mem_RAMREG_4_G[1]_s0

Path Statistics:

Clock Skew | -0.007
Setup Relationship | 20.000
Logic Level | 17
Arrival Clock Path Delay | cell: 1.288, 36.076%; route: 2.283, 63.924%
Arrival Data Path Delay | cell: 5.153, 34.233%; route: 9.625, 63.937%; tC2Q: 0.275, 1.829%
Required Clock Path Delay | cell: 1.288, 36.144%; route: 2.276, 63.856%

### Path15

Path Summary:

Slack | 4.690
Data Arrival Time | 18.657
Data Required Time | 23.347
From | g_sound.u_seq_arb/cnt_q_0_s0
To | g_sound.u_seq_arb/mem_mem_RAMREG_6_G[32]_s0
Launch Clk | clk_sys:[R]
Latch Clk | clk_sys:[R]

Data Arrival Path:

AT | DELAY | TYPE | RF | FANOUT | LOC | NODE
0.000 | 0.000 | | | | | active clock edge time
0.000 | 0.000 | | | | | clk_sys
0.000 | 0.000 | tCL | RR | 1 | IOB117[B] | clk_ibuf/I
1.288 | 1.288 | tINS | RR | 15763 | IOB117[B] | clk_ibuf/O
3.571 | 2.283 | tNET | RR | 1 | R45C51[0][B] | g_sound.u_seq_arb/cnt_q_0_s0/CLK
3.847 | 0.275 | tC2Q | RR | 6 | R45C51[0][B] | g_sound.u_seq_arb/cnt_q_0_s0/Q
4.243 | 0.396 | tNET | RR | 1 | R46C53[0][A] | g_sound.u_seq_arb/cnt_after_pop_5_s1/I0
4.575 | 0.332 | tINS | RR | 5 | R46C53[0][A] | g_sound.u_seq_arb/cnt_after_pop_5_s1/F
4.889 | 0.314 | tNET | RR | 1 | R48C54[2][B] | g_sound.u_seq_arb/cnt_after_pop_8_s1/I3
5.078 | 0.189 | tINS | RR | 5 | R48C54[2][B] | g_sound.u_seq_arb/cnt_after_pop_8_s1/F
5.419 | 0.341 | tNET | RR | 1 | R46C53[3][B] | g_sound.u_seq_arb/cnt_after_pop_11_s1/I3
5.777 | 0.358 | tINS | RR | 5 | R46C53[3][B] | g_sound.u_seq_arb/cnt_after_pop_11_s1/F
6.130 | 0.353 | tNET | RR | 1 | R44C54[2][B] | g_sound.u_seq_arb/cnt_after_pop_13_s2/I3
6.462 | 0.332 | tINS | RR | 5 | R44C54[2][B] | g_sound.u_seq_arb/cnt_after_pop_13_s2/F
6.854 | 0.392 | tNET | RR | 1 | R45C52[1][A] | g_sound.u_seq_arb/pop_now_s2/I3
7.186 | 0.332 | tINS | RR | 82 | R45C52[1][A] | g_sound.u_seq_arb/pop_now_s2/F
10.110 | 2.924 | tNET | RR | 1 | R48C54[3][B] | g_sound.u_seq_arb/cnt_after_pop_6_s1/I3
10.485 | 0.375 | tINS | RR | 2 | R48C54[3][B] | g_sound.u_seq_arb/cnt_after_pop_6_s1/F
10.489 | 0.004 | tNET | RR | 1 | R48C54[1][B] | g_sound.u_seq_arb/cnt_after_pop_6_s0/I0
10.868 | 0.379 | tINS | RR | 1 | R48C54[1][B] | g_sound.u_seq_arb/cnt_after_pop_6_s0/F
11.313 | 0.446 | tNET | RR | 2 | R45C55[0][A] | g_sound.u_seq_arb/cnt_next_6_s/I1
11.668 | 0.355 | tINS | RR | 1 | R45C55[0][A] | g_sound.u_seq_arb/cnt_next_6_s/COUT
11.668 | 0.000 | tNET | RR | 2 | R45C55[0][B] | g_sound.u_seq_arb/cnt_next_7_s/CIN
11.704 | 0.036 | tINS | RR | 1 | R45C55[0][B] | g_sound.u_seq_arb/cnt_next_7_s/COUT
11.704 | 0.000 | tNET | RR | 2 | R45C55[1][A] | g_sound.u_seq_arb/cnt_next_8_s/CIN
11.740 | 0.036 | tINS | RR | 1 | R45C55[1][A] | g_sound.u_seq_arb/cnt_next_8_s/COUT
11.740 | 0.000 | tNET | RR | 2 | R45C55[1][B] | g_sound.u_seq_arb/cnt_next_9_s/CIN
11.776 | 0.036 | tINS | RR | 1 | R45C55[1][B] | g_sound.u_seq_arb/cnt_next_9_s/COUT
11.776 | 0.000 | tNET | RR | 2 | R45C55[2][A] | g_sound.u_seq_arb/cnt_next_10_s/CIN
11.812 | 0.036 | tINS | RR | 1 | R45C55[2][A] | g_sound.u_seq_arb/cnt_next_10_s/COUT
11.812 | 0.000 | tNET | RR | 2 | R45C55[2][B] | g_sound.u_seq_arb/cnt_next_11_s/CIN
11.848 | 0.036 | tINS | RR | 1 | R45C55[2][B] | g_sound.u_seq_arb/cnt_next_11_s/COUT
11.848 | 0.000 | tNET | RR | 2 | R45C56[0][A] | g_sound.u_seq_arb/cnt_next_12_s/CIN
11.884 | 0.036 | tINS | RR | 1 | R45C56[0][A] | g_sound.u_seq_arb/cnt_next_12_s/COUT
11.884 | 0.000 | tNET | RR | 2 | R45C56[0][B] | g_sound.u_seq_arb/cnt_next_13_s/CIN
12.101 | 0.217 | tINS | RF | 1 | R45C56[0][B] | g_sound.u_seq_arb/cnt_next_13_s/SUM
12.264 | 0.163 | tNET | FF | 1 | R45C54[3][A] | g_sound.u_seq_arb/n2344_s5/I0
12.639 | 0.375 | tINS | FR | 1 | R45C54[3][A] | g_sound.u_seq_arb/n2344_s5/F
12.753 | 0.113 | tNET | RR | 1 | R45C53[0][A] | g_sound.u_seq_arb/n2344_s2/I2
13.124 | 0.372 | tINS | RR | 13 | R45C53[0][A] | g_sound.u_seq_arb/n2344_s2/F
13.975 | 0.850 | tNET | RR | 1 | R36C62[3][A] | g_sound.u_seq_arb/mem_s3115/I1
14.274 | 0.299 | tINS | RR | 2 | R36C62[3][A] | g_sound.u_seq_arb/mem_s3115/F
14.374 | 0.101 | tNET | RR | 1 | R36C62[3][B] | g_sound.u_seq_arb/mem_s3036/I3
14.733 | 0.358 | tINS | RR | 5 | R36C62[3][B] | g_sound.u_seq_arb/mem_s3036/F
15.310 | 0.578 | tNET | RR | 1 | R35C59[2][B] | g_sound.u_seq_arb/mem_s3296/I2
15.642 | 0.332 | tINS | RR | 40 | R35C59[2][B] | g_sound.u_seq_arb/mem_s3296/F
17.173 | 1.531 | tNET | RR | 1 | R48C64[2][A] | g_sound.u_seq_arb/mem_s2734/I0
17.362 | 0.189 | tINS | RR | 29 | R48C64[2][A] | g_sound.u_seq_arb/mem_s2734/F
18.657 | 1.295 | tNET | RR | 1 | R44C59[0][A] | g_sound.u_seq_arb/mem_mem_RAMREG_6_G[32]_s0/CE

Data Required Path:

AT | DELAY | TYPE | RF | FANOUT | LOC | NODE
20.000 | 20.000 | | | | | active clock edge time
20.000 | 0.000 | | | | | clk_sys
20.000 | 0.000 | tCL | RR | 1 | IOB117[B] | clk_ibuf/I
21.288 | 1.288 | tINS | RR | 15763 | IOB117[B] | clk_ibuf/O
23.571 | 2.283 | tNET | RR | 1 | R44C59[0][A] | g_sound.u_seq_arb/mem_mem_RAMREG_6_G[32]_s0/CLK
23.347 | -0.224 | tSu | | 1 | R44C59[0][A] | g_sound.u_seq_arb/mem_mem_RAMREG_6_G[32]_s0

Path Statistics:

Clock Skew | 0.000
Setup Relationship | 20.000
Logic Level | 17
Arrival Clock Path Delay | cell: 1.288, 36.076%; route: 2.283, 63.924%
Arrival Data Path Delay | cell: 5.010, 33.211%; route: 9.801, 64.963%; tC2Q: 0.275, 1.826%
Required Clock Path Delay | cell: 1.288, 36.076%; route: 2.283, 63.924%

### Path16

Path Summary:

Slack | 4.708
Data Arrival Time | 18.661
Data Required Time | 23.368
From | g_sound.u_note_manager/env_active_r_1_s0
To | g_sound.u_note_manager/vtgt_vld_vtgt_vld_RAMREG_7_G[0]_s0
Launch Clk | clk_sys:[R]
Latch Clk | clk_sys:[R]

Data Arrival Path:

AT | DELAY | TYPE | RF | FANOUT | LOC | NODE
0.000 | 0.000 | | | | | active clock edge time
0.000 | 0.000 | | | | | clk_sys
0.000 | 0.000 | tCL | RR | 1 | IOB117[B] | clk_ibuf/I
1.288 | 1.288 | tINS | RR | 15763 | IOB117[B] | clk_ibuf/O
3.928 | 2.639 | tNET | RR | 1 | R36C13[0][A] | g_sound.u_note_manager/env_active_r_1_s0/CLK
4.203 | 0.275 | tC2Q | RR | 3 | R36C13[0][A] | g_sound.u_note_manager/env_active_r_1_s0/Q
9.473 | 5.270 | tNET | RR | 1 | R31C126[2][A] | g_sound.u_note_manager/cand_free_s63/I2
9.805 | 0.332 | tINS | RR | 10 | R31C126[2][A] | g_sound.u_note_manager/cand_free_s63/F
11.730 | 1.924 | tNET | RR | 1 | R17C134[2][A] | g_sound.u_note_manager/same_idx_0_s4/I2
12.109 | 0.379 | tINS | RR | 3 | R17C134[2][A] | g_sound.u_note_manager/same_idx_0_s4/F
12.706 | 0.598 | tNET | RR | 1 | R17C122[3][B] | g_sound.u_note_manager/same_idx_1_s19/I0
13.081 | 0.375 | tINS | RR | 3 | R17C122[3][B] | g_sound.u_note_manager/same_idx_1_s19/F
13.724 | 0.643 | tNET | RR | 1 | R17C115[1][A] | g_sound.u_note_manager/same_idx_3_s12/I2
14.103 | 0.379 | tINS | RR | 3 | R17C115[1][A] | g_sound.u_note_manager/same_idx_3_s12/F
14.108 | 0.005 | tNET | RR | 1 | R17C115[2][B] | g_sound.u_note_manager/same_valid_s4/I0
14.297 | 0.189 | tINS | RR | 1 | R17C115[2][B] | g_sound.u_note_manager/same_valid_s4/F
14.548 | 0.250 | tNET | RR | 1 | R16C116[3][B] | g_sound.u_note_manager/same_valid_s0/I3
14.923 | 0.375 | tINS | RR | 4 | R16C116[3][B] | g_sound.u_note_manager/same_valid_s0/F
15.504 | 0.581 | tNET | RR | 1 | R16C131[3][B] | g_sound.u_note_manager/n22713_s10/I2
15.862 | 0.358 | tINS | RR | 4 | R16C131[3][B] | g_sound.u_note_manager/n22713_s10/F
16.313 | 0.451 | tNET | RR | 1 | R8C132[0][B] | g_sound.u_note_manager/vtgt_vld_s371/I1
16.645 | 0.332 | tINS | RR | 16 | R8C132[0][B] | g_sound.u_note_manager/vtgt_vld_s371/F
18.039 | 1.393 | tNET | RR | 1 | R8C122[3][A] | g_sound.u_note_manager/vtgt_vld_s355/I0
18.247 | 0.209 | tINS | RF | 1 | R8C122[3][A] | g_sound.u_note_manager/vtgt_vld_s355/F
18.661 | 0.413 | tNET | FF | 1 | R12C121[2][B] | g_sound.u_note_manager/vtgt_vld_vtgt_vld_RAMREG_7_G[0]_s0/D

Data Required Path:

AT | DELAY | TYPE | RF | FANOUT | LOC | NODE
20.000 | 20.000 | | | | | active clock edge time
20.000 | 0.000 | | | | | clk_sys
20.000 | 0.000 | tCL | RR | 1 | IOB117[B] | clk_ibuf/I
21.288 | 1.288 | tINS | RR | 15763 | IOB117[B] | clk_ibuf/O
23.578 | 2.290 | tNET | RR | 1 | R12C121[2][B] | g_sound.u_note_manager/vtgt_vld_vtgt_vld_RAMREG_7_G[0]_s0/CLK
23.368 | -0.210 | tSu | | 1 | R12C121[2][B] | g_sound.u_note_manager/vtgt_vld_vtgt_vld_RAMREG_7_G[0]_s0

Path Statistics:

Clock Skew | -0.350
Setup Relationship | 20.000
Logic Level | 10
Arrival Clock Path Delay | cell: 1.288, 32.802%; route: 2.639, 67.198%
Arrival Data Path Delay | cell: 2.929, 19.878%; route: 11.529, 78.253%; tC2Q: 0.275, 1.869%
Required Clock Path Delay | cell: 1.288, 36.008%; route: 2.290, 63.992%

### Path17

Path Summary:

Slack | 4.722
Data Arrival Time | 18.625
Data Required Time | 23.347
From | g_sound.u_seq_arb/cnt_q_0_s0
To | g_sound.u_seq_arb/mem_mem_RAMREG_0_G[32]_s0
Launch Clk | clk_sys:[R]
Latch Clk | clk_sys:[R]

Data Arrival Path:

AT | DELAY | TYPE | RF | FANOUT | LOC | NODE
0.000 | 0.000 | | | | | active clock edge time
0.000 | 0.000 | | | | | clk_sys
0.000 | 0.000 | tCL | RR | 1 | IOB117[B] | clk_ibuf/I
1.288 | 1.288 | tINS | RR | 15763 | IOB117[B] | clk_ibuf/O
3.571 | 2.283 | tNET | RR | 1 | R45C51[0][B] | g_sound.u_seq_arb/cnt_q_0_s0/CLK
3.847 | 0.275 | tC2Q | RR | 6 | R45C51[0][B] | g_sound.u_seq_arb/cnt_q_0_s0/Q
4.243 | 0.396 | tNET | RR | 1 | R46C53[0][A] | g_sound.u_seq_arb/cnt_after_pop_5_s1/I0
4.575 | 0.332 | tINS | RR | 5 | R46C53[0][A] | g_sound.u_seq_arb/cnt_after_pop_5_s1/F
4.889 | 0.314 | tNET | RR | 1 | R48C54[2][B] | g_sound.u_seq_arb/cnt_after_pop_8_s1/I3
5.078 | 0.189 | tINS | RR | 5 | R48C54[2][B] | g_sound.u_seq_arb/cnt_after_pop_8_s1/F
5.419 | 0.341 | tNET | RR | 1 | R46C53[3][B] | g_sound.u_seq_arb/cnt_after_pop_11_s1/I3
5.777 | 0.358 | tINS | RR | 5 | R46C53[3][B] | g_sound.u_seq_arb/cnt_after_pop_11_s1/F
6.130 | 0.353 | tNET | RR | 1 | R44C54[2][B] | g_sound.u_seq_arb/cnt_after_pop_13_s2/I3
6.462 | 0.332 | tINS | RR | 5 | R44C54[2][B] | g_sound.u_seq_arb/cnt_after_pop_13_s2/F
6.854 | 0.392 | tNET | RR | 1 | R45C52[1][A] | g_sound.u_seq_arb/pop_now_s2/I3
7.186 | 0.332 | tINS | RR | 82 | R45C52[1][A] | g_sound.u_seq_arb/pop_now_s2/F
10.110 | 2.924 | tNET | RR | 1 | R48C54[3][B] | g_sound.u_seq_arb/cnt_after_pop_6_s1/I3
10.485 | 0.375 | tINS | RR | 2 | R48C54[3][B] | g_sound.u_seq_arb/cnt_after_pop_6_s1/F
10.489 | 0.004 | tNET | RR | 1 | R48C54[1][B] | g_sound.u_seq_arb/cnt_after_pop_6_s0/I0
10.868 | 0.379 | tINS | RR | 1 | R48C54[1][B] | g_sound.u_seq_arb/cnt_after_pop_6_s0/F
11.313 | 0.446 | tNET | RR | 2 | R45C55[0][A] | g_sound.u_seq_arb/cnt_next_6_s/I1
11.668 | 0.355 | tINS | RR | 1 | R45C55[0][A] | g_sound.u_seq_arb/cnt_next_6_s/COUT
11.668 | 0.000 | tNET | RR | 2 | R45C55[0][B] | g_sound.u_seq_arb/cnt_next_7_s/CIN
11.704 | 0.036 | tINS | RR | 1 | R45C55[0][B] | g_sound.u_seq_arb/cnt_next_7_s/COUT
11.704 | 0.000 | tNET | RR | 2 | R45C55[1][A] | g_sound.u_seq_arb/cnt_next_8_s/CIN
11.740 | 0.036 | tINS | RR | 1 | R45C55[1][A] | g_sound.u_seq_arb/cnt_next_8_s/COUT
11.740 | 0.000 | tNET | RR | 2 | R45C55[1][B] | g_sound.u_seq_arb/cnt_next_9_s/CIN
11.776 | 0.036 | tINS | RR | 1 | R45C55[1][B] | g_sound.u_seq_arb/cnt_next_9_s/COUT
11.776 | 0.000 | tNET | RR | 2 | R45C55[2][A] | g_sound.u_seq_arb/cnt_next_10_s/CIN
11.812 | 0.036 | tINS | RR | 1 | R45C55[2][A] | g_sound.u_seq_arb/cnt_next_10_s/COUT
11.812 | 0.000 | tNET | RR | 2 | R45C55[2][B] | g_sound.u_seq_arb/cnt_next_11_s/CIN
11.848 | 0.036 | tINS | RR | 1 | R45C55[2][B] | g_sound.u_seq_arb/cnt_next_11_s/COUT
11.848 | 0.000 | tNET | RR | 2 | R45C56[0][A] | g_sound.u_seq_arb/cnt_next_12_s/CIN
11.884 | 0.036 | tINS | RR | 1 | R45C56[0][A] | g_sound.u_seq_arb/cnt_next_12_s/COUT
11.884 | 0.000 | tNET | RR | 2 | R45C56[0][B] | g_sound.u_seq_arb/cnt_next_13_s/CIN
12.101 | 0.217 | tINS | RF | 1 | R45C56[0][B] | g_sound.u_seq_arb/cnt_next_13_s/SUM
12.264 | 0.163 | tNET | FF | 1 | R45C54[3][A] | g_sound.u_seq_arb/n2344_s5/I0
12.639 | 0.375 | tINS | FR | 1 | R45C54[3][A] | g_sound.u_seq_arb/n2344_s5/F
12.753 | 0.113 | tNET | RR | 1 | R45C53[0][A] | g_sound.u_seq_arb/n2344_s2/I2
13.124 | 0.372 | tINS | RR | 13 | R45C53[0][A] | g_sound.u_seq_arb/n2344_s2/F
13.975 | 0.850 | tNET | RR | 1 | R36C62[3][A] | g_sound.u_seq_arb/mem_s3115/I1
14.274 | 0.299 | tINS | RR | 2 | R36C62[3][A] | g_sound.u_seq_arb/mem_s3115/F
14.374 | 0.101 | tNET | RR | 1 | R36C62[3][B] | g_sound.u_seq_arb/mem_s3036/I3
14.733 | 0.358 | tINS | RR | 5 | R36C62[3][B] | g_sound.u_seq_arb/mem_s3036/F
15.310 | 0.578 | tNET | RR | 1 | R35C59[2][A] | g_sound.u_seq_arb/mem_s2747/I3
15.642 | 0.332 | tINS | RR | 43 | R35C59[2][A] | g_sound.u_seq_arb/mem_s2747/F
17.546 | 1.903 | tNET | RR | 1 | R44C55[3][A] | g_sound.u_seq_arb/mem_s2722/I0
17.921 | 0.375 | tINS | RR | 29 | R44C55[3][A] | g_sound.u_seq_arb/mem_s2722/F
18.625 | 0.704 | tNET | RR | 1 | R42C61[1][B] | g_sound.u_seq_arb/mem_mem_RAMREG_0_G[32]_s0/CE

Data Required Path:

AT | DELAY | TYPE | RF | FANOUT | LOC | NODE
20.000 | 20.000 | | | | | active clock edge time
20.000 | 0.000 | | | | | clk_sys
20.000 | 0.000 | tCL | RR | 1 | IOB117[B] | clk_ibuf/I
21.288 | 1.288 | tINS | RR | 15763 | IOB117[B] | clk_ibuf/O
23.571 | 2.283 | tNET | RR | 1 | R42C61[1][B] | g_sound.u_seq_arb/mem_mem_RAMREG_0_G[32]_s0/CLK
23.347 | -0.224 | tSu | | 1 | R42C61[1][B] | g_sound.u_seq_arb/mem_mem_RAMREG_0_G[32]_s0

Path Statistics:

Clock Skew | 0.000
Setup Relationship | 20.000
Logic Level | 17
Arrival Clock Path Delay | cell: 1.288, 36.076%; route: 2.283, 63.924%
Arrival Data Path Delay | cell: 5.197, 34.520%; route: 9.582, 63.650%; tC2Q: 0.275, 1.829%
Required Clock Path Delay | cell: 1.288, 36.076%; route: 2.283, 63.924%

### Path18

Path Summary:

Slack | 4.722
Data Arrival Time | 18.625
Data Required Time | 23.347
From | g_sound.u_seq_arb/cnt_q_0_s0
To | g_sound.u_seq_arb/mem_mem_RAMREG_0_G[31]_s0
Launch Clk | clk_sys:[R]
Latch Clk | clk_sys:[R]

Data Arrival Path:

AT | DELAY | TYPE | RF | FANOUT | LOC | NODE
0.000 | 0.000 | | | | | active clock edge time
0.000 | 0.000 | | | | | clk_sys
0.000 | 0.000 | tCL | RR | 1 | IOB117[B] | clk_ibuf/I
1.288 | 1.288 | tINS | RR | 15763 | IOB117[B] | clk_ibuf/O
3.571 | 2.283 | tNET | RR | 1 | R45C51[0][B] | g_sound.u_seq_arb/cnt_q_0_s0/CLK
3.847 | 0.275 | tC2Q | RR | 6 | R45C51[0][B] | g_sound.u_seq_arb/cnt_q_0_s0/Q
4.243 | 0.396 | tNET | RR | 1 | R46C53[0][A] | g_sound.u_seq_arb/cnt_after_pop_5_s1/I0
4.575 | 0.332 | tINS | RR | 5 | R46C53[0][A] | g_sound.u_seq_arb/cnt_after_pop_5_s1/F
4.889 | 0.314 | tNET | RR | 1 | R48C54[2][B] | g_sound.u_seq_arb/cnt_after_pop_8_s1/I3
5.078 | 0.189 | tINS | RR | 5 | R48C54[2][B] | g_sound.u_seq_arb/cnt_after_pop_8_s1/F
5.419 | 0.341 | tNET | RR | 1 | R46C53[3][B] | g_sound.u_seq_arb/cnt_after_pop_11_s1/I3
5.777 | 0.358 | tINS | RR | 5 | R46C53[3][B] | g_sound.u_seq_arb/cnt_after_pop_11_s1/F
6.130 | 0.353 | tNET | RR | 1 | R44C54[2][B] | g_sound.u_seq_arb/cnt_after_pop_13_s2/I3
6.462 | 0.332 | tINS | RR | 5 | R44C54[2][B] | g_sound.u_seq_arb/cnt_after_pop_13_s2/F
6.854 | 0.392 | tNET | RR | 1 | R45C52[1][A] | g_sound.u_seq_arb/pop_now_s2/I3
7.186 | 0.332 | tINS | RR | 82 | R45C52[1][A] | g_sound.u_seq_arb/pop_now_s2/F
10.110 | 2.924 | tNET | RR | 1 | R48C54[3][B] | g_sound.u_seq_arb/cnt_after_pop_6_s1/I3
10.485 | 0.375 | tINS | RR | 2 | R48C54[3][B] | g_sound.u_seq_arb/cnt_after_pop_6_s1/F
10.489 | 0.004 | tNET | RR | 1 | R48C54[1][B] | g_sound.u_seq_arb/cnt_after_pop_6_s0/I0
10.868 | 0.379 | tINS | RR | 1 | R48C54[1][B] | g_sound.u_seq_arb/cnt_after_pop_6_s0/F
11.313 | 0.446 | tNET | RR | 2 | R45C55[0][A] | g_sound.u_seq_arb/cnt_next_6_s/I1
11.668 | 0.355 | tINS | RR | 1 | R45C55[0][A] | g_sound.u_seq_arb/cnt_next_6_s/COUT
11.668 | 0.000 | tNET | RR | 2 | R45C55[0][B] | g_sound.u_seq_arb/cnt_next_7_s/CIN
11.704 | 0.036 | tINS | RR | 1 | R45C55[0][B] | g_sound.u_seq_arb/cnt_next_7_s/COUT
11.704 | 0.000 | tNET | RR | 2 | R45C55[1][A] | g_sound.u_seq_arb/cnt_next_8_s/CIN
11.740 | 0.036 | tINS | RR | 1 | R45C55[1][A] | g_sound.u_seq_arb/cnt_next_8_s/COUT
11.740 | 0.000 | tNET | RR | 2 | R45C55[1][B] | g_sound.u_seq_arb/cnt_next_9_s/CIN
11.776 | 0.036 | tINS | RR | 1 | R45C55[1][B] | g_sound.u_seq_arb/cnt_next_9_s/COUT
11.776 | 0.000 | tNET | RR | 2 | R45C55[2][A] | g_sound.u_seq_arb/cnt_next_10_s/CIN
11.812 | 0.036 | tINS | RR | 1 | R45C55[2][A] | g_sound.u_seq_arb/cnt_next_10_s/COUT
11.812 | 0.000 | tNET | RR | 2 | R45C55[2][B] | g_sound.u_seq_arb/cnt_next_11_s/CIN
11.848 | 0.036 | tINS | RR | 1 | R45C55[2][B] | g_sound.u_seq_arb/cnt_next_11_s/COUT
11.848 | 0.000 | tNET | RR | 2 | R45C56[0][A] | g_sound.u_seq_arb/cnt_next_12_s/CIN
11.884 | 0.036 | tINS | RR | 1 | R45C56[0][A] | g_sound.u_seq_arb/cnt_next_12_s/COUT
11.884 | 0.000 | tNET | RR | 2 | R45C56[0][B] | g_sound.u_seq_arb/cnt_next_13_s/CIN
12.101 | 0.217 | tINS | RF | 1 | R45C56[0][B] | g_sound.u_seq_arb/cnt_next_13_s/SUM
12.264 | 0.163 | tNET | FF | 1 | R45C54[3][A] | g_sound.u_seq_arb/n2344_s5/I0
12.639 | 0.375 | tINS | FR | 1 | R45C54[3][A] | g_sound.u_seq_arb/n2344_s5/F
12.753 | 0.113 | tNET | RR | 1 | R45C53[0][A] | g_sound.u_seq_arb/n2344_s2/I2
13.124 | 0.372 | tINS | RR | 13 | R45C53[0][A] | g_sound.u_seq_arb/n2344_s2/F
13.975 | 0.850 | tNET | RR | 1 | R36C62[3][A] | g_sound.u_seq_arb/mem_s3115/I1
14.274 | 0.299 | tINS | RR | 2 | R36C62[3][A] | g_sound.u_seq_arb/mem_s3115/F
14.374 | 0.101 | tNET | RR | 1 | R36C62[3][B] | g_sound.u_seq_arb/mem_s3036/I3
14.733 | 0.358 | tINS | RR | 5 | R36C62[3][B] | g_sound.u_seq_arb/mem_s3036/F
15.310 | 0.578 | tNET | RR | 1 | R35C59[2][A] | g_sound.u_seq_arb/mem_s2747/I3
15.642 | 0.332 | tINS | RR | 43 | R35C59[2][A] | g_sound.u_seq_arb/mem_s2747/F
17.546 | 1.903 | tNET | RR | 1 | R44C55[3][A] | g_sound.u_seq_arb/mem_s2722/I0
17.921 | 0.375 | tINS | RR | 29 | R44C55[3][A] | g_sound.u_seq_arb/mem_s2722/F
18.625 | 0.704 | tNET | RR | 1 | R42C61[1][A] | g_sound.u_seq_arb/mem_mem_RAMREG_0_G[31]_s0/CE

Data Required Path:

AT | DELAY | TYPE | RF | FANOUT | LOC | NODE
20.000 | 20.000 | | | | | active clock edge time
20.000 | 0.000 | | | | | clk_sys
20.000 | 0.000 | tCL | RR | 1 | IOB117[B] | clk_ibuf/I
21.288 | 1.288 | tINS | RR | 15763 | IOB117[B] | clk_ibuf/O
23.571 | 2.283 | tNET | RR | 1 | R42C61[1][A] | g_sound.u_seq_arb/mem_mem_RAMREG_0_G[31]_s0/CLK
23.347 | -0.224 | tSu | | 1 | R42C61[1][A] | g_sound.u_seq_arb/mem_mem_RAMREG_0_G[31]_s0

Path Statistics:

Clock Skew | 0.000
Setup Relationship | 20.000
Logic Level | 17
Arrival Clock Path Delay | cell: 1.288, 36.076%; route: 2.283, 63.924%
Arrival Data Path Delay | cell: 5.197, 34.520%; route: 9.582, 63.650%; tC2Q: 0.275, 1.829%
Required Clock Path Delay | cell: 1.288, 36.076%; route: 2.283, 63.924%

### Path19

Path Summary:

Slack | 4.722
Data Arrival Time | 18.625
Data Required Time | 23.347
From | g_sound.u_seq_arb/cnt_q_0_s0
To | g_sound.u_seq_arb/mem_mem_RAMREG_0_G[28]_s0
Launch Clk | clk_sys:[R]
Latch Clk | clk_sys:[R]

Data Arrival Path:

AT | DELAY | TYPE | RF | FANOUT | LOC | NODE
0.000 | 0.000 | | | | | active clock edge time
0.000 | 0.000 | | | | | clk_sys
0.000 | 0.000 | tCL | RR | 1 | IOB117[B] | clk_ibuf/I
1.288 | 1.288 | tINS | RR | 15763 | IOB117[B] | clk_ibuf/O
3.571 | 2.283 | tNET | RR | 1 | R45C51[0][B] | g_sound.u_seq_arb/cnt_q_0_s0/CLK
3.847 | 0.275 | tC2Q | RR | 6 | R45C51[0][B] | g_sound.u_seq_arb/cnt_q_0_s0/Q
4.243 | 0.396 | tNET | RR | 1 | R46C53[0][A] | g_sound.u_seq_arb/cnt_after_pop_5_s1/I0
4.575 | 0.332 | tINS | RR | 5 | R46C53[0][A] | g_sound.u_seq_arb/cnt_after_pop_5_s1/F
4.889 | 0.314 | tNET | RR | 1 | R48C54[2][B] | g_sound.u_seq_arb/cnt_after_pop_8_s1/I3
5.078 | 0.189 | tINS | RR | 5 | R48C54[2][B] | g_sound.u_seq_arb/cnt_after_pop_8_s1/F
5.419 | 0.341 | tNET | RR | 1 | R46C53[3][B] | g_sound.u_seq_arb/cnt_after_pop_11_s1/I3
5.777 | 0.358 | tINS | RR | 5 | R46C53[3][B] | g_sound.u_seq_arb/cnt_after_pop_11_s1/F
6.130 | 0.353 | tNET | RR | 1 | R44C54[2][B] | g_sound.u_seq_arb/cnt_after_pop_13_s2/I3
6.462 | 0.332 | tINS | RR | 5 | R44C54[2][B] | g_sound.u_seq_arb/cnt_after_pop_13_s2/F
6.854 | 0.392 | tNET | RR | 1 | R45C52[1][A] | g_sound.u_seq_arb/pop_now_s2/I3
7.186 | 0.332 | tINS | RR | 82 | R45C52[1][A] | g_sound.u_seq_arb/pop_now_s2/F
10.110 | 2.924 | tNET | RR | 1 | R48C54[3][B] | g_sound.u_seq_arb/cnt_after_pop_6_s1/I3
10.485 | 0.375 | tINS | RR | 2 | R48C54[3][B] | g_sound.u_seq_arb/cnt_after_pop_6_s1/F
10.489 | 0.004 | tNET | RR | 1 | R48C54[1][B] | g_sound.u_seq_arb/cnt_after_pop_6_s0/I0
10.868 | 0.379 | tINS | RR | 1 | R48C54[1][B] | g_sound.u_seq_arb/cnt_after_pop_6_s0/F
11.313 | 0.446 | tNET | RR | 2 | R45C55[0][A] | g_sound.u_seq_arb/cnt_next_6_s/I1
11.668 | 0.355 | tINS | RR | 1 | R45C55[0][A] | g_sound.u_seq_arb/cnt_next_6_s/COUT
11.668 | 0.000 | tNET | RR | 2 | R45C55[0][B] | g_sound.u_seq_arb/cnt_next_7_s/CIN
11.704 | 0.036 | tINS | RR | 1 | R45C55[0][B] | g_sound.u_seq_arb/cnt_next_7_s/COUT
11.704 | 0.000 | tNET | RR | 2 | R45C55[1][A] | g_sound.u_seq_arb/cnt_next_8_s/CIN
11.740 | 0.036 | tINS | RR | 1 | R45C55[1][A] | g_sound.u_seq_arb/cnt_next_8_s/COUT
11.740 | 0.000 | tNET | RR | 2 | R45C55[1][B] | g_sound.u_seq_arb/cnt_next_9_s/CIN
11.776 | 0.036 | tINS | RR | 1 | R45C55[1][B] | g_sound.u_seq_arb/cnt_next_9_s/COUT
11.776 | 0.000 | tNET | RR | 2 | R45C55[2][A] | g_sound.u_seq_arb/cnt_next_10_s/CIN
11.812 | 0.036 | tINS | RR | 1 | R45C55[2][A] | g_sound.u_seq_arb/cnt_next_10_s/COUT
11.812 | 0.000 | tNET | RR | 2 | R45C55[2][B] | g_sound.u_seq_arb/cnt_next_11_s/CIN
11.848 | 0.036 | tINS | RR | 1 | R45C55[2][B] | g_sound.u_seq_arb/cnt_next_11_s/COUT
11.848 | 0.000 | tNET | RR | 2 | R45C56[0][A] | g_sound.u_seq_arb/cnt_next_12_s/CIN
11.884 | 0.036 | tINS | RR | 1 | R45C56[0][A] | g_sound.u_seq_arb/cnt_next_12_s/COUT
11.884 | 0.000 | tNET | RR | 2 | R45C56[0][B] | g_sound.u_seq_arb/cnt_next_13_s/CIN
12.101 | 0.217 | tINS | RF | 1 | R45C56[0][B] | g_sound.u_seq_arb/cnt_next_13_s/SUM
12.264 | 0.163 | tNET | FF | 1 | R45C54[3][A] | g_sound.u_seq_arb/n2344_s5/I0
12.639 | 0.375 | tINS | FR | 1 | R45C54[3][A] | g_sound.u_seq_arb/n2344_s5/F
12.753 | 0.113 | tNET | RR | 1 | R45C53[0][A] | g_sound.u_seq_arb/n2344_s2/I2
13.124 | 0.372 | tINS | RR | 13 | R45C53[0][A] | g_sound.u_seq_arb/n2344_s2/F
13.975 | 0.850 | tNET | RR | 1 | R36C62[3][A] | g_sound.u_seq_arb/mem_s3115/I1
14.274 | 0.299 | tINS | RR | 2 | R36C62[3][A] | g_sound.u_seq_arb/mem_s3115/F
14.374 | 0.101 | tNET | RR | 1 | R36C62[3][B] | g_sound.u_seq_arb/mem_s3036/I3
14.733 | 0.358 | tINS | RR | 5 | R36C62[3][B] | g_sound.u_seq_arb/mem_s3036/F
15.310 | 0.578 | tNET | RR | 1 | R35C59[2][A] | g_sound.u_seq_arb/mem_s2747/I3
15.642 | 0.332 | tINS | RR | 43 | R35C59[2][A] | g_sound.u_seq_arb/mem_s2747/F
17.546 | 1.903 | tNET | RR | 1 | R44C55[3][A] | g_sound.u_seq_arb/mem_s2722/I0
17.921 | 0.375 | tINS | RR | 29 | R44C55[3][A] | g_sound.u_seq_arb/mem_s2722/F
18.625 | 0.704 | tNET | RR | 1 | R42C61[0][B] | g_sound.u_seq_arb/mem_mem_RAMREG_0_G[28]_s0/CE

Data Required Path:

AT | DELAY | TYPE | RF | FANOUT | LOC | NODE
20.000 | 20.000 | | | | | active clock edge time
20.000 | 0.000 | | | | | clk_sys
20.000 | 0.000 | tCL | RR | 1 | IOB117[B] | clk_ibuf/I
21.288 | 1.288 | tINS | RR | 15763 | IOB117[B] | clk_ibuf/O
23.571 | 2.283 | tNET | RR | 1 | R42C61[0][B] | g_sound.u_seq_arb/mem_mem_RAMREG_0_G[28]_s0/CLK
23.347 | -0.224 | tSu | | 1 | R42C61[0][B] | g_sound.u_seq_arb/mem_mem_RAMREG_0_G[28]_s0

Path Statistics:

Clock Skew | 0.000
Setup Relationship | 20.000
Logic Level | 17
Arrival Clock Path Delay | cell: 1.288, 36.076%; route: 2.283, 63.924%
Arrival Data Path Delay | cell: 5.197, 34.520%; route: 9.582, 63.650%; tC2Q: 0.275, 1.829%
Required Clock Path Delay | cell: 1.288, 36.076%; route: 2.283, 63.924%

### Path20

Path Summary:

Slack | 4.722
Data Arrival Time | 18.625
Data Required Time | 23.347
From | g_sound.u_seq_arb/cnt_q_0_s0
To | g_sound.u_seq_arb/mem_mem_RAMREG_0_G[20]_s0
Launch Clk | clk_sys:[R]
Latch Clk | clk_sys:[R]

Data Arrival Path:

AT | DELAY | TYPE | RF | FANOUT | LOC | NODE
0.000 | 0.000 | | | | | active clock edge time
0.000 | 0.000 | | | | | clk_sys
0.000 | 0.000 | tCL | RR | 1 | IOB117[B] | clk_ibuf/I
1.288 | 1.288 | tINS | RR | 15763 | IOB117[B] | clk_ibuf/O
3.571 | 2.283 | tNET | RR | 1 | R45C51[0][B] | g_sound.u_seq_arb/cnt_q_0_s0/CLK
3.847 | 0.275 | tC2Q | RR | 6 | R45C51[0][B] | g_sound.u_seq_arb/cnt_q_0_s0/Q
4.243 | 0.396 | tNET | RR | 1 | R46C53[0][A] | g_sound.u_seq_arb/cnt_after_pop_5_s1/I0
4.575 | 0.332 | tINS | RR | 5 | R46C53[0][A] | g_sound.u_seq_arb/cnt_after_pop_5_s1/F
4.889 | 0.314 | tNET | RR | 1 | R48C54[2][B] | g_sound.u_seq_arb/cnt_after_pop_8_s1/I3
5.078 | 0.189 | tINS | RR | 5 | R48C54[2][B] | g_sound.u_seq_arb/cnt_after_pop_8_s1/F
5.419 | 0.341 | tNET | RR | 1 | R46C53[3][B] | g_sound.u_seq_arb/cnt_after_pop_11_s1/I3
5.777 | 0.358 | tINS | RR | 5 | R46C53[3][B] | g_sound.u_seq_arb/cnt_after_pop_11_s1/F
6.130 | 0.353 | tNET | RR | 1 | R44C54[2][B] | g_sound.u_seq_arb/cnt_after_pop_13_s2/I3
6.462 | 0.332 | tINS | RR | 5 | R44C54[2][B] | g_sound.u_seq_arb/cnt_after_pop_13_s2/F
6.854 | 0.392 | tNET | RR | 1 | R45C52[1][A] | g_sound.u_seq_arb/pop_now_s2/I3
7.186 | 0.332 | tINS | RR | 82 | R45C52[1][A] | g_sound.u_seq_arb/pop_now_s2/F
10.110 | 2.924 | tNET | RR | 1 | R48C54[3][B] | g_sound.u_seq_arb/cnt_after_pop_6_s1/I3
10.485 | 0.375 | tINS | RR | 2 | R48C54[3][B] | g_sound.u_seq_arb/cnt_after_pop_6_s1/F
10.489 | 0.004 | tNET | RR | 1 | R48C54[1][B] | g_sound.u_seq_arb/cnt_after_pop_6_s0/I0
10.868 | 0.379 | tINS | RR | 1 | R48C54[1][B] | g_sound.u_seq_arb/cnt_after_pop_6_s0/F
11.313 | 0.446 | tNET | RR | 2 | R45C55[0][A] | g_sound.u_seq_arb/cnt_next_6_s/I1
11.668 | 0.355 | tINS | RR | 1 | R45C55[0][A] | g_sound.u_seq_arb/cnt_next_6_s/COUT
11.668 | 0.000 | tNET | RR | 2 | R45C55[0][B] | g_sound.u_seq_arb/cnt_next_7_s/CIN
11.704 | 0.036 | tINS | RR | 1 | R45C55[0][B] | g_sound.u_seq_arb/cnt_next_7_s/COUT
11.704 | 0.000 | tNET | RR | 2 | R45C55[1][A] | g_sound.u_seq_arb/cnt_next_8_s/CIN
11.740 | 0.036 | tINS | RR | 1 | R45C55[1][A] | g_sound.u_seq_arb/cnt_next_8_s/COUT
11.740 | 0.000 | tNET | RR | 2 | R45C55[1][B] | g_sound.u_seq_arb/cnt_next_9_s/CIN
11.776 | 0.036 | tINS | RR | 1 | R45C55[1][B] | g_sound.u_seq_arb/cnt_next_9_s/COUT
11.776 | 0.000 | tNET | RR | 2 | R45C55[2][A] | g_sound.u_seq_arb/cnt_next_10_s/CIN
11.812 | 0.036 | tINS | RR | 1 | R45C55[2][A] | g_sound.u_seq_arb/cnt_next_10_s/COUT
11.812 | 0.000 | tNET | RR | 2 | R45C55[2][B] | g_sound.u_seq_arb/cnt_next_11_s/CIN
11.848 | 0.036 | tINS | RR | 1 | R45C55[2][B] | g_sound.u_seq_arb/cnt_next_11_s/COUT
11.848 | 0.000 | tNET | RR | 2 | R45C56[0][A] | g_sound.u_seq_arb/cnt_next_12_s/CIN
11.884 | 0.036 | tINS | RR | 1 | R45C56[0][A] | g_sound.u_seq_arb/cnt_next_12_s/COUT
11.884 | 0.000 | tNET | RR | 2 | R45C56[0][B] | g_sound.u_seq_arb/cnt_next_13_s/CIN
12.101 | 0.217 | tINS | RF | 1 | R45C56[0][B] | g_sound.u_seq_arb/cnt_next_13_s/SUM
12.264 | 0.163 | tNET | FF | 1 | R45C54[3][A] | g_sound.u_seq_arb/n2344_s5/I0
12.639 | 0.375 | tINS | FR | 1 | R45C54[3][A] | g_sound.u_seq_arb/n2344_s5/F
12.753 | 0.113 | tNET | RR | 1 | R45C53[0][A] | g_sound.u_seq_arb/n2344_s2/I2
13.124 | 0.372 | tINS | RR | 13 | R45C53[0][A] | g_sound.u_seq_arb/n2344_s2/F
13.975 | 0.850 | tNET | RR | 1 | R36C62[3][A] | g_sound.u_seq_arb/mem_s3115/I1
14.274 | 0.299 | tINS | RR | 2 | R36C62[3][A] | g_sound.u_seq_arb/mem_s3115/F
14.374 | 0.101 | tNET | RR | 1 | R36C62[3][B] | g_sound.u_seq_arb/mem_s3036/I3
14.733 | 0.358 | tINS | RR | 5 | R36C62[3][B] | g_sound.u_seq_arb/mem_s3036/F
15.310 | 0.578 | tNET | RR | 1 | R35C59[2][A] | g_sound.u_seq_arb/mem_s2747/I3
15.642 | 0.332 | tINS | RR | 43 | R35C59[2][A] | g_sound.u_seq_arb/mem_s2747/F
17.546 | 1.903 | tNET | RR | 1 | R44C55[3][A] | g_sound.u_seq_arb/mem_s2722/I0
17.921 | 0.375 | tINS | RR | 29 | R44C55[3][A] | g_sound.u_seq_arb/mem_s2722/F
18.625 | 0.704 | tNET | RR | 1 | R43C61[1][A] | g_sound.u_seq_arb/mem_mem_RAMREG_0_G[20]_s0/CE

Data Required Path:

AT | DELAY | TYPE | RF | FANOUT | LOC | NODE
20.000 | 20.000 | | | | | active clock edge time
20.000 | 0.000 | | | | | clk_sys
20.000 | 0.000 | tCL | RR | 1 | IOB117[B] | clk_ibuf/I
21.288 | 1.288 | tINS | RR | 15763 | IOB117[B] | clk_ibuf/O
23.571 | 2.283 | tNET | RR | 1 | R43C61[1][A] | g_sound.u_seq_arb/mem_mem_RAMREG_0_G[20]_s0/CLK
23.347 | -0.224 | tSu | | 1 | R43C61[1][A] | g_sound.u_seq_arb/mem_mem_RAMREG_0_G[20]_s0

Path Statistics:

Clock Skew | 0.000
Setup Relationship | 20.000
Logic Level | 17
Arrival Clock Path Delay | cell: 1.288, 36.076%; route: 2.283, 63.924%
Arrival Data Path Delay | cell: 5.197, 34.520%; route: 9.582, 63.650%; tC2Q: 0.275, 1.829%
Required Clock Path Delay | cell: 1.288, 36.076%; route: 2.283, 63.924%

### Path21

Path Summary:

Slack | 4.724
Data Arrival Time | 18.623
Data Required Time | 23.347
From | g_sound.u_evt_merge/cnt_q_0_s0
To | g_sound.u_evt_merge/mem_mem_RAMREG_5_G[26]_s0
Launch Clk | clk_sys:[R]
Latch Clk | clk_sys:[R]

Data Arrival Path:

AT | DELAY | TYPE | RF | FANOUT | LOC | NODE
0.000 | 0.000 | | | | | active clock edge time
0.000 | 0.000 | | | | | clk_sys
0.000 | 0.000 | tCL | RR | 1 | IOB117[B] | clk_ibuf/I
1.288 | 1.288 | tINS | RR | 15763 | IOB117[B] | clk_ibuf/O
3.571 | 2.283 | tNET | RR | 1 | R61C51[1][B] | g_sound.u_evt_merge/cnt_q_0_s0/CLK
3.847 | 0.275 | tC2Q | RR | 6 | R61C51[1][B] | g_sound.u_evt_merge/cnt_q_0_s0/Q
3.967 | 0.121 | tNET | RR | 1 | R60C51[2][B] | g_sound.u_evt_merge/cnt_after_pop_5_s1/I0
4.346 | 0.379 | tINS | RR | 5 | R60C51[2][B] | g_sound.u_evt_merge/cnt_after_pop_5_s1/F
4.755 | 0.409 | tNET | RR | 1 | R60C47[2][B] | g_sound.u_evt_merge/cnt_after_pop_8_s1/I3
5.126 | 0.372 | tINS | RR | 5 | R60C47[2][B] | g_sound.u_evt_merge/cnt_after_pop_8_s1/F
5.132 | 0.005 | tNET | RR | 1 | R60C47[3][B] | g_sound.u_evt_merge/cnt_after_pop_11_s1/I3
5.490 | 0.358 | tINS | RR | 5 | R60C47[3][B] | g_sound.u_evt_merge/cnt_after_pop_11_s1/F
5.609 | 0.119 | tNET | RR | 1 | R59C47[0][A] | g_sound.u_evt_merge/cnt_after_pop_13_s2/I3
5.798 | 0.189 | tINS | RR | 5 | R59C47[0][A] | g_sound.u_evt_merge/cnt_after_pop_13_s2/F
5.944 | 0.146 | tNET | RR | 1 | R59C49[3][B] | g_sound.u_evt_merge/pop_now_s2/I3
6.134 | 0.191 | tINS | RR | 89 | R59C49[3][B] | g_sound.u_evt_merge/pop_now_s2/F
8.273 | 2.138 | tNET | RR | 1 | R60C51[2][A] | g_sound.u_evt_merge/cnt_after_pop_3_s1/I3
8.605 | 0.332 | tINS | RR | 2 | R60C51[2][A] | g_sound.u_evt_merge/cnt_after_pop_3_s1/F
8.720 | 0.115 | tNET | RR | 1 | R61C51[3][A] | g_sound.u_evt_merge/cnt_after_pop_3_s0/I0
8.911 | 0.191 | tINS | RR | 1 | R61C51[3][A] | g_sound.u_evt_merge/cnt_after_pop_3_s0/F
9.487 | 0.576 | tNET | RR | 2 | R61C45[1][B] | g_sound.u_evt_merge/cnt_next_3_s/I1
9.841 | 0.355 | tINS | RR | 1 | R61C45[1][B] | g_sound.u_evt_merge/cnt_next_3_s/COUT
9.841 | 0.000 | tNET | RR | 2 | R61C45[2][A] | g_sound.u_evt_merge/cnt_next_4_s/CIN
9.877 | 0.036 | tINS | RR | 1 | R61C45[2][A] | g_sound.u_evt_merge/cnt_next_4_s/COUT
9.877 | 0.000 | tNET | RR | 2 | R61C45[2][B] | g_sound.u_evt_merge/cnt_next_5_s/CIN
9.913 | 0.036 | tINS | RR | 1 | R61C45[2][B] | g_sound.u_evt_merge/cnt_next_5_s/COUT
9.913 | 0.000 | tNET | RR | 2 | R61C46[0][A] | g_sound.u_evt_merge/cnt_next_6_s/CIN
9.949 | 0.036 | tINS | RR | 1 | R61C46[0][A] | g_sound.u_evt_merge/cnt_next_6_s/COUT
9.949 | 0.000 | tNET | RR | 2 | R61C46[0][B] | g_sound.u_evt_merge/cnt_next_7_s/CIN
9.985 | 0.036 | tINS | RR | 1 | R61C46[0][B] | g_sound.u_evt_merge/cnt_next_7_s/COUT
9.985 | 0.000 | tNET | RR | 2 | R61C46[1][A] | g_sound.u_evt_merge/cnt_next_8_s/CIN
10.021 | 0.036 | tINS | RR | 1 | R61C46[1][A] | g_sound.u_evt_merge/cnt_next_8_s/COUT
10.021 | 0.000 | tNET | RR | 2 | R61C46[1][B] | g_sound.u_evt_merge/cnt_next_9_s/CIN
10.057 | 0.036 | tINS | RR | 1 | R61C46[1][B] | g_sound.u_evt_merge/cnt_next_9_s/COUT
10.057 | 0.000 | tNET | RR | 2 | R61C46[2][A] | g_sound.u_evt_merge/cnt_next_10_s/CIN
10.093 | 0.036 | tINS | RR | 1 | R61C46[2][A] | g_sound.u_evt_merge/cnt_next_10_s/COUT
10.093 | 0.000 | tNET | RR | 2 | R61C46[2][B] | g_sound.u_evt_merge/cnt_next_11_s/CIN
10.129 | 0.036 | tINS | RR | 1 | R61C46[2][B] | g_sound.u_evt_merge/cnt_next_11_s/COUT
10.129 | 0.000 | tNET | RR | 2 | R61C47[0][A] | g_sound.u_evt_merge/cnt_next_12_s/CIN
10.305 | 0.175 | tINS | RR | 1 | R61C47[0][A] | g_sound.u_evt_merge/cnt_next_12_s/SUM
10.573 | 0.268 | tNET | RR | 1 | R62C46[3][A] | g_sound.u_evt_merge/n1433_s3/I0
10.931 | 0.358 | tINS | RR | 1 | R62C46[3][A] | g_sound.u_evt_merge/n1433_s3/F
11.182 | 0.250 | tNET | RR | 1 | R61C45[3][A] | g_sound.u_evt_merge/n1433_s2/I2
11.557 | 0.375 | tINS | RR | 1 | R61C45[3][A] | g_sound.u_evt_merge/n1433_s2/F
11.825 | 0.268 | tNET | RR | 1 | R61C47[3][A] | g_sound.u_evt_merge/n1433_s1/I3
12.034 | 0.209 | tINS | RF | 1 | R61C47[3][A] | g_sound.u_evt_merge/n1433_s1/F
12.037 | 0.004 | tNET | FF | 1 | R61C47[2][B] | g_sound.u_evt_merge/n1433_s0/I3
12.370 | 0.332 | tINS | FR | 38 | R61C47[2][B] | g_sound.u_evt_merge/n1433_s0/F
13.089 | 0.719 | tNET | RR | 1 | R64C49[3][B] | g_sound.u_evt_merge/mem_s3593/I3
13.297 | 0.209 | tINS | RF | 1 | R64C49[3][B] | g_sound.u_evt_merge/mem_s3593/F
13.301 | 0.004 | tNET | FF | 1 | R64C49[0][B] | g_sound.u_evt_merge/mem_s3570/I2
13.680 | 0.379 | tINS | FR | 8 | R64C49[0][B] | g_sound.u_evt_merge/mem_s3570/F
14.230 | 0.550 | tNET | RR | 1 | R67C48[1][B] | g_sound.u_evt_merge/mem_s3546/I2
14.602 | 0.372 | tINS | RR | 70 | R67C48[1][B] | g_sound.u_evt_merge/mem_s3546/F
14.872 | 0.270 | tNET | RR | 1 | R66C49[0][B] | g_sound.u_evt_merge/mem_s3661/I3
15.204 | 0.332 | tINS | RR | 13 | R66C49[0][B] | g_sound.u_evt_merge/mem_s3661/F
15.817 | 0.614 | tNET | RR | 1 | R72C52[0][B] | g_sound.u_evt_merge/mem_s3083/I1
16.189 | 0.372 | tINS | RR | 50 | R72C52[0][B] | g_sound.u_evt_merge/mem_s3083/F
18.623 | 2.434 | tNET | RR | 1 | R52C47[1][A] | g_sound.u_evt_merge/mem_mem_RAMREG_5_G[26]_s0/CE

Data Required Path:

AT | DELAY | TYPE | RF | FANOUT | LOC | NODE
20.000 | 20.000 | | | | | active clock edge time
20.000 | 0.000 | | | | | clk_sys
20.000 | 0.000 | tCL | RR | 1 | IOB117[B] | clk_ibuf/I
21.288 | 1.288 | tINS | RR | 15763 | IOB117[B] | clk_ibuf/O
23.571 | 2.283 | tNET | RR | 1 | R52C47[1][A] | g_sound.u_evt_merge/mem_mem_RAMREG_5_G[26]_s0/CLK
23.347 | -0.224 | tSu | | 1 | R52C47[1][A] | g_sound.u_evt_merge/mem_mem_RAMREG_5_G[26]_s0

Path Statistics:

Clock Skew | 0.000
Setup Relationship | 20.000
Logic Level | 20
Arrival Clock Path Delay | cell: 1.288, 36.076%; route: 2.283, 63.924%
Arrival Data Path Delay | cell: 5.767, 38.316%; route: 9.009, 59.854%; tC2Q: 0.275, 1.830%
Required Clock Path Delay | cell: 1.288, 36.076%; route: 2.283, 63.924%

### Path22

Path Summary:

Slack | 4.729
Data Arrival Time | 18.618
Data Required Time | 23.347
From | g_sound.u_seq_arb/cnt_q_0_s0
To | g_sound.u_seq_arb/mem_mem_RAMREG_0_G[12]_s0
Launch Clk | clk_sys:[R]
Latch Clk | clk_sys:[R]

Data Arrival Path:

AT | DELAY | TYPE | RF | FANOUT | LOC | NODE
0.000 | 0.000 | | | | | active clock edge time
0.000 | 0.000 | | | | | clk_sys
0.000 | 0.000 | tCL | RR | 1 | IOB117[B] | clk_ibuf/I
1.288 | 1.288 | tINS | RR | 15763 | IOB117[B] | clk_ibuf/O
3.571 | 2.283 | tNET | RR | 1 | R45C51[0][B] | g_sound.u_seq_arb/cnt_q_0_s0/CLK
3.847 | 0.275 | tC2Q | RR | 6 | R45C51[0][B] | g_sound.u_seq_arb/cnt_q_0_s0/Q
4.243 | 0.396 | tNET | RR | 1 | R46C53[0][A] | g_sound.u_seq_arb/cnt_after_pop_5_s1/I0
4.575 | 0.332 | tINS | RR | 5 | R46C53[0][A] | g_sound.u_seq_arb/cnt_after_pop_5_s1/F
4.889 | 0.314 | tNET | RR | 1 | R48C54[2][B] | g_sound.u_seq_arb/cnt_after_pop_8_s1/I3
5.078 | 0.189 | tINS | RR | 5 | R48C54[2][B] | g_sound.u_seq_arb/cnt_after_pop_8_s1/F
5.419 | 0.341 | tNET | RR | 1 | R46C53[3][B] | g_sound.u_seq_arb/cnt_after_pop_11_s1/I3
5.777 | 0.358 | tINS | RR | 5 | R46C53[3][B] | g_sound.u_seq_arb/cnt_after_pop_11_s1/F
6.130 | 0.353 | tNET | RR | 1 | R44C54[2][B] | g_sound.u_seq_arb/cnt_after_pop_13_s2/I3
6.462 | 0.332 | tINS | RR | 5 | R44C54[2][B] | g_sound.u_seq_arb/cnt_after_pop_13_s2/F
6.854 | 0.392 | tNET | RR | 1 | R45C52[1][A] | g_sound.u_seq_arb/pop_now_s2/I3
7.186 | 0.332 | tINS | RR | 82 | R45C52[1][A] | g_sound.u_seq_arb/pop_now_s2/F
10.110 | 2.924 | tNET | RR | 1 | R48C54[3][B] | g_sound.u_seq_arb/cnt_after_pop_6_s1/I3
10.485 | 0.375 | tINS | RR | 2 | R48C54[3][B] | g_sound.u_seq_arb/cnt_after_pop_6_s1/F
10.489 | 0.004 | tNET | RR | 1 | R48C54[1][B] | g_sound.u_seq_arb/cnt_after_pop_6_s0/I0
10.868 | 0.379 | tINS | RR | 1 | R48C54[1][B] | g_sound.u_seq_arb/cnt_after_pop_6_s0/F
11.313 | 0.446 | tNET | RR | 2 | R45C55[0][A] | g_sound.u_seq_arb/cnt_next_6_s/I1
11.668 | 0.355 | tINS | RR | 1 | R45C55[0][A] | g_sound.u_seq_arb/cnt_next_6_s/COUT
11.668 | 0.000 | tNET | RR | 2 | R45C55[0][B] | g_sound.u_seq_arb/cnt_next_7_s/CIN
11.704 | 0.036 | tINS | RR | 1 | R45C55[0][B] | g_sound.u_seq_arb/cnt_next_7_s/COUT
11.704 | 0.000 | tNET | RR | 2 | R45C55[1][A] | g_sound.u_seq_arb/cnt_next_8_s/CIN
11.740 | 0.036 | tINS | RR | 1 | R45C55[1][A] | g_sound.u_seq_arb/cnt_next_8_s/COUT
11.740 | 0.000 | tNET | RR | 2 | R45C55[1][B] | g_sound.u_seq_arb/cnt_next_9_s/CIN
11.776 | 0.036 | tINS | RR | 1 | R45C55[1][B] | g_sound.u_seq_arb/cnt_next_9_s/COUT
11.776 | 0.000 | tNET | RR | 2 | R45C55[2][A] | g_sound.u_seq_arb/cnt_next_10_s/CIN
11.812 | 0.036 | tINS | RR | 1 | R45C55[2][A] | g_sound.u_seq_arb/cnt_next_10_s/COUT
11.812 | 0.000 | tNET | RR | 2 | R45C55[2][B] | g_sound.u_seq_arb/cnt_next_11_s/CIN
11.848 | 0.036 | tINS | RR | 1 | R45C55[2][B] | g_sound.u_seq_arb/cnt_next_11_s/COUT
11.848 | 0.000 | tNET | RR | 2 | R45C56[0][A] | g_sound.u_seq_arb/cnt_next_12_s/CIN
11.884 | 0.036 | tINS | RR | 1 | R45C56[0][A] | g_sound.u_seq_arb/cnt_next_12_s/COUT
11.884 | 0.000 | tNET | RR | 2 | R45C56[0][B] | g_sound.u_seq_arb/cnt_next_13_s/CIN
12.101 | 0.217 | tINS | RF | 1 | R45C56[0][B] | g_sound.u_seq_arb/cnt_next_13_s/SUM
12.264 | 0.163 | tNET | FF | 1 | R45C54[3][A] | g_sound.u_seq_arb/n2344_s5/I0
12.639 | 0.375 | tINS | FR | 1 | R45C54[3][A] | g_sound.u_seq_arb/n2344_s5/F
12.753 | 0.113 | tNET | RR | 1 | R45C53[0][A] | g_sound.u_seq_arb/n2344_s2/I2
13.124 | 0.372 | tINS | RR | 13 | R45C53[0][A] | g_sound.u_seq_arb/n2344_s2/F
13.975 | 0.850 | tNET | RR | 1 | R36C62[3][A] | g_sound.u_seq_arb/mem_s3115/I1
14.274 | 0.299 | tINS | RR | 2 | R36C62[3][A] | g_sound.u_seq_arb/mem_s3115/F
14.374 | 0.101 | tNET | RR | 1 | R36C62[3][B] | g_sound.u_seq_arb/mem_s3036/I3
14.733 | 0.358 | tINS | RR | 5 | R36C62[3][B] | g_sound.u_seq_arb/mem_s3036/F
15.310 | 0.578 | tNET | RR | 1 | R35C59[2][A] | g_sound.u_seq_arb/mem_s2747/I3
15.642 | 0.332 | tINS | RR | 43 | R35C59[2][A] | g_sound.u_seq_arb/mem_s2747/F
17.546 | 1.903 | tNET | RR | 1 | R44C55[3][A] | g_sound.u_seq_arb/mem_s2722/I0
17.921 | 0.375 | tINS | RR | 29 | R44C55[3][A] | g_sound.u_seq_arb/mem_s2722/F
18.618 | 0.697 | tNET | RR | 1 | R46C61[0][B] | g_sound.u_seq_arb/mem_mem_RAMREG_0_G[12]_s0/CE

Data Required Path:

AT | DELAY | TYPE | RF | FANOUT | LOC | NODE
20.000 | 20.000 | | | | | active clock edge time
20.000 | 0.000 | | | | | clk_sys
20.000 | 0.000 | tCL | RR | 1 | IOB117[B] | clk_ibuf/I
21.288 | 1.288 | tINS | RR | 15763 | IOB117[B] | clk_ibuf/O
23.571 | 2.283 | tNET | RR | 1 | R46C61[0][B] | g_sound.u_seq_arb/mem_mem_RAMREG_0_G[12]_s0/CLK
23.347 | -0.224 | tSu | | 1 | R46C61[0][B] | g_sound.u_seq_arb/mem_mem_RAMREG_0_G[12]_s0

Path Statistics:

Clock Skew | 0.000
Setup Relationship | 20.000
Logic Level | 17
Arrival Clock Path Delay | cell: 1.288, 36.076%; route: 2.283, 63.924%
Arrival Data Path Delay | cell: 5.197, 34.537%; route: 9.575, 63.633%; tC2Q: 0.275, 1.830%
Required Clock Path Delay | cell: 1.288, 36.076%; route: 2.283, 63.924%
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
