hokuu1102/Gowin2026-PolySynth/bringup/README.md

# 🧪 `bringup/` —— 验证与上板（⛔ **不放成品代码**）

> ⭐ **这个文件夹是干什么的**：把"**验证**"这件事单独放一处 —— 写清楚
> **现在这份代码到底能验什么、已经验过什么、还缺什么才能验**，
> 以及**板子到手后**按什么顺序上板验证。
>
> ⛔ **边界**（用户 2026-09-17 明确要求）：
> · 这里**不放成品 RTL**（成品在 `rtl/`）· 也不放验收判据的"正式版"文档（那些在 `files/20-代码/`）
> · 这里放：**验证清单 / 上板方案 / 上板专用顶层与约束 / 上板用脚本**
> · 目的：**交付代码保持干净**，验证相关的临时件、只用于上板的顶层、PC 侧脚本不污染 `rtl/`

---

## 一、目录索引

| 文件 | 内容 | 什么时候看 |
|---|---|---|
| ⭐ `01-现有代码能验证什么.md` | **逐文件**：它保证什么 / **✅已经验过什么（带证据路径）** / 🟡**还能验但还没做** / ⛔**现在验不了（缺什么）** | 想知道"我这份代码站不站得住"时 |
| ⭐ `02-基石板上板验证方案.md` | 手上那块基石板**能验什么、不能验什么**；引脚（有实测依据）；**上板阶梯 0~6**；上板专属坑清单 | 准备动板子 / 排"仿真过、上板错"时 |
| `run_all.ps1` | ⭐ **一条命令跑完"今天就能跑的所有验证"**，打印一张验收矩阵 | 每次改完代码 / 推送前 |
| ⭐⭐ `mutation_test.ps1` | ⭐ **变异测试**：每次注入一处**已知缺陷**，要求回归**必须变红** ⇒ 证明"判据不是摆设"（当前 **18/18 全被抓**：12 个改 RTL + 4 个改判据自身 + 2 条手册约束） | 改完判据/检查器后；⚠️ 见文件头的使用纪律 |
| `03-对抗式审查与修复记录.md` | 20 条审查发现的**修复台账** + tools 独立审查 + **变异测试结果** | 想知道"修过什么、凭什么说修好了" |
| ⭐⭐ `04-基石板上板验证指南.md` | ⭐ **用手上已有的基石板**验证最底层三件事（时钟/复位/I2S）—— 一条龙命令、**逐级期望现象**、故障定位表、**以及"这一级验不到什么"** | ⭐ **板子到手后第一件事** |
| ⭐⭐ `jishi/` | ⭐ **基石板上板工程**（独立工程：`jishi_top.v` + `jishi.cst` + `jishi.sdc` + `jishi.gprj` + `build_jishi.ps1` + `probe_balls.ps1`）。⛔ **不碰正式代码**，用**相对路径**引用同一份 `rtl/` | 上板；换 ball 时用 `probe_balls.ps1` **探测**（⛔ 别猜） |

---

## 二、当前状态一句话（2026-09-17）

- **能跑的验证**：仿真回归 `sim/tb_all.ps1` **11/11**、工具自检 `python tools\selftest_all.py` **4/4**、
  ⭐ **变异测试 `mutation_test.ps1` 18/18 全被抓**、
  Gowin 全流程（`sim/gowin_build.ps1`）**综合+布局布线+bitstream 全过、时序违规端点 0、引脚 7/7 落位**；
  ⚠️ 注意 **`Fmax` 有两个口径**：只写 `create_clock` 时 325.9 MHz（**漏检引脚路径**），
  ⭐ **补上 I/O 约束后 = 55.96 MHz（真实可达）** —— 见 `K-53`。
- ⭐⭐ **基石板上板工程也跑通了**（`jishi/`，2026-09-17）：综合+PnR+bitstream **exit 0**、
  **时序违规 0**、`Actual Fmax 55.258 MHz`（含 I/O 约束）、**7 个脚全部落位**（含 `beep` 的 `PULL_MODE=DOWN`）。
  ⇒ ⭐ **板子一到手就能烧**（见 `04`）。
- **板子现状**：左右手板**刚投板、无实物**；最终要用的 Dock 板**预计国庆之后到手**；
  手上只有**高云 60K 基石板**（有 UART / ADA107 的 10bit DAC+ADC / 蜂鸣器 / LED / 按键，**没有音频 DAC**）。
- **所以现在的验证形态是**：**仿真 + 工具链**（不用板）为主；
  基石板能补上"**真实硅片**"这一层（见 `02`），补不上的是 Dock 的 PT8211/功放/时钟脚那一段。

---

## 三、一条命令

```powershell
# 今天就能跑的全部验证（仿真 + 工具自检）
powershell -NoProfile -ExecutionPolicy Bypass -File bringup\run_all.ps1

# 加上 Gowin 全流程（多花约 2 分钟；会写 impl/，但 impl/ 已被 gitignore）
powershell -NoProfile -ExecutionPolicy Bypass -File bringup\run_all.ps1 -WithGowin
```

> ⚠️ `run_all.ps1` **故意写成全 ASCII**：本机 PowerShell 5.1 会把无 BOM 的 UTF-8 按 GBK 解码，
> 中文注释会变乱码并报语法错（见经验库 `U46` / `files/20-代码/已知问题与风险清单.md` `K-38`）。
