hokuu1102/Gowin2026-PolySynth/bringup/40-推子三档与双颤音共存-实施方案-20261018.md

# 推子三档 + 双颤音共存 + 锁定 —— 实施方案（2026-10-18）

> **状态**：计划稿，待实施。⛔ 未改任何 RTL。
> **前置**：本文只写"怎么改 + 为什么"，判据与分工见 §六/§七。

---

## 一、目标（用户 2026-10-17/18 裁定）

| # | 目标 | 原话依据 |
|---|---|---|
| 1 | 推子三档：**0=变调 · 1=音高颤音 · 2=音量颤音** | "0是变调，1是音高颤音，2是音量颤音" |
| 2 | 两个颤音**可以共存**（切档时保持，不清零） | "如果两个能共存的话，我还是希望都能在串口屏上显示" |
| 3 | 加**锁定键**：冻结当前档，推子回 0 后值不变 | "加一个按键，让推子记忆当前档位此时的状态，再按一下取消记忆" |
| 4 | 屏点选 ⇒ **推子自动切到该档** | "串口屏点一下，推子切换到当前档位" |
| 5 | 屏**纯显示 + 选对象**，⛔ 不改值 | "串口屏本身不参与参数调节" |
| 6 | 时序目标放松：`set_max_delay 16.4 → 18.0` | "B" |

---

## 二、⭐ 逻辑梳理：先确认工作流成立

### 2.1 用户的完整操作流

```
① 屏点 [音高颤音]      → 推子切档 1（第 3 颗灯变青）
② 推 ch2 到目标深度    → 实时听到颤音
③ 按【锁定键】         → 档 1 冻结
④ 推子回 0             → 颤音保持（因为锁了）
⑤ 屏点 [音量颤音]      → 切档 2，推子从 0 开始 ⇒ 不跳变
⑥ 重复 ②③④
⑦ 切 [变调]            → 两推子都在 0 ⇒ 不变调，可实时调音高
```

### 2.2 ⭐ 一个关键发现：变调是**双推子差分**，不是绝对位置

`fader_gear.v:143-149`（已核）：

```verilog
wire [3:0] left_step  = gear_step_of(ch2_i);   // 左推子 0..12
wire [3:0] right_step = gear_step_of(ch3_i);   // 右推子 0..12
wire [5:0] fader_enc6 = 6'd12 + right_step - left_step;   // 0..24，12 = 不变调
```

⇒ **两个推子都在 0 ⇒ `12 + 0 − 0 = 12` ⇒ 不变调** ✅
⇒ **所以"推子回 0"对变调档正好是中性位** —— 用户第 ⑦ 步的直觉是对的，切到变调**不会**一来就降八度。

⚠️ 但要注意语义在档之间**不一致**：
| 档 | ch2 的含义 | ch3 的含义 |
|---|---|---|
| 0 变调 | 左（参与差分） | 右（参与差分） |
| 1 音高颤音 | 深度（绝对） | 速率（绝对） |
| 2 音量颤音 | 深度（绝对） | 速率（绝对） |

⇒ 这正是"必须锁定"的根因：档 1/2 是绝对值，推子回 0 就等于关掉。

---

## 三、⭐ 逻辑问题清单（实施前必须逐条处置）

| # | 问题 | 处置 | 状态 |
|---|---|---|---|
| **L1** | 档 1/2 是绝对值 ⇒ 推子回 0 会把颤音关掉 | 加**每档锁定位** | ✅ 已定 |
| **L2** | 解锁那一刻会不会跳？ | **会**跳到推子当前位置（因为推子停在 0 ⇒ 值归 0）。这是**预期行为**：解锁 = "我现在接管"。⚠️ 必须写进手册 | ✅ 已定 |
| **L3** | 档 0 的"进档接管"（`gear0_enter`）会无视锁定 | 接管条件加 `&& !hold_r[0]` | ⚠️ 必改 |
| **L4** | 上电默认锁定状态？ | ⭐ **用户裁定：上电【全解锁】**（`hold_o` 复位 = `3'b000`）⇒ 三档都实时跟随推子。⚠️ 前提：推子应停在 0（两推子都在 0 ⇒ 变调中性、两个颤音深度 0） | ✅ 已定 |
| **L5** | 音量颤音的 rate 是 8 位，推子是 12 位 | `rate = ch3[11:7]`（0..31）。依据：`fx_trem.RATE_DEFAULT = 7 ≈ 5 Hz`；若直接 `[11:4]` 前 3% 行程就覆盖全部常用区，手感极差 | ✅ 已定 |
| **L6** | 音量颤音的 depth 也是 8 位 | `depth = ch2[11:4]`（0..255，全行程有意义；255 = 最深） | ✅ 已定 |
| **L7** | 音高颤音是 12 位，直接透传 | 不变（档 1 逐位透传 `ch2_i`/`ch3_i`，与现状逐位相同） | ✅ 已定 |
| **L8** | `led_indicator` **没有呼吸机制** | 🔴 实测：注释 `:211-212` 明写"呼吸要额外做正弦/三角调制，属将来优化"，只有 `BL_FAST`（快闪）。⇒ **改用快闪**表示锁定，⛔ 不新做呼吸 | ⚠️ 方案调整 |
| **L9** | 锁定键加进 `ctrl_key_map` 的 EX2000 风险 | 新增输出必须**单一 always 驱动**（该项目已踩过 EX2000 多驱动，见 AGENTS.md 四之二①） | ⚠️ 必查 |
| **L10** | 屏上显示"生效值"还是"推子值" | 必须显示**生效值**（锁定后的值），否则用户看到推子动了数字不动会以为坏了 | ⚠️ 必写清 |
| **L11** | `tb_fader_gear` 的 G 组判据会大面积失效 | 判据 e/f/g/i 从"清零"改"保持"；新增锁定判据；`gear 0⇄1` 改三档循环 | ⚠️ 必重写 |
| **L12** | 三档循环后，`'J'` 从"切一下"变成"切三下回原位" | 保留 `'J'`/矩阵 idx5 作循环；**屏点选是直接跳档**（走 `gear_sel2_i` 一类输入） | ✅ 已定 |

---

## 四、接口定义（⭐ 先定死，子代理才能并行）

### 4.1 `rtl/w3a/fader_gear.v` 新端口

```verilog
module fader_gear (
    // ── 现有端口全部保留（⛔ 不改名、不改宽）──
    ...
    // ── 新增 ──
    input  wire        gear_sel2_i,     // 屏点选：直接跳档 2（单周期脉冲）
    input  wire        gear_sel1_i,     // 屏点选：直接跳档 1（单周期脉冲）
    input  wire        gear_sel0_i,     // 屏点选：直接跳档 0（单周期脉冲）
    input  wire        lock_toggle_i,   // 锁定键：翻转【当前档】的锁定位（单周期脉冲）
    output reg  [11:0] trem_depth_o,    // 档 2 = ch2_i 透传（音量颤音深度）
    output reg  [11:0] trem_rate_o,     // 档 2 = ch3_i 透传（音量颤音速率）
    output reg  [2:0]  hold_o           // 三档锁定状态（bit0/1/2 对应档 0/1/2），给 LED/屏
);
```

**优先级（同拍时）**：`gear_sel0/1/2` > `gear_next_i`（循环） > 保持。

### 4.2 行为表（⭐ 这是全案的契约）

| 条件 | `transpose_semi_o` | `vibrato_depth_o/rate_o` | `trem_depth_o/rate_o` | `gear_o` |
|---|---|---|---|---|
| 复位 | 0（enc=12） | 0 / 0 | 0 / 0 | 1 |
| 档 0 且 `!hold[0]` | 跟随 `fader_enc` | **保持** | **保持** | 0 |
| 档 0 且 `hold[0]` | **保持** | **保持** | **保持** | 0 |
| 档 1 且 `!hold[1]` | 保持 | `ch2_i` / `ch3_i` | **保持** | 1 |
| 档 1 且 `hold[1]` | 保持 | **保持** | **保持** | 1 |
| 档 2 且 `!hold[2]` | 保持 | **保持** | `ch2_i` / `ch3_i` | 2 |
| 档 2 且 `hold[2]` | 保持 | **保持** | **保持** | 2 |
| 复位后 | `hold_o = 3'b000`（**全解锁**，用户裁定） | 0 | 0 | 1 |

**"保持"的实现（关键：⛔ 不能破坏档 1 的零延迟透传）**：

```verilog
// 档 1 时逐位透传（组合），离开档 1 时用影子寄存器保持
always @(posedge clk)
    if (!rst_n)                 begin vib_d_hold <= 12'd0; vib_r_hold <= 12'd0; end
    else if (gear_o == 2'd1 && !hold[1]) begin vib_d_hold <= ch2_i; vib_r_hold <= ch3_i; end

wire [11:0] vib_d_eff = (gear_o == 2'd1 && !hold[1]) ? ch2_i : vib_d_hold;
```

⇒ 档 1 时**组合透传**（与现状逐位相同 ✅）；离开或锁定时读影子寄存器（保持）。

档 2 的 `trem_*` 同构。

档 0 的 `enc_r` 保持：现有 `else enc_next = enc_r` 已经是"保持"，只需把接管条件改成 `(fader_moved || gear0_enter) && !hold[0]`。

---

## 五、文件改动清单

| # | 文件 | 改什么 | 谁 |
|---|---|---|---|
| 1 | `rtl/w3a/fader_gear.v` | 新端口（§4.1）；三档循环；锁定位；`trem_*` 输出；档 0 接管加 `!hold[0]` | 子代理 A |
| 2 | `rtl/top.v` | 接 `trem_*` → `fx_chain.trem_*` 的 2:1 mux（档 2 时推子独占）；接 `lock_toggle_i`；接 `gear_sel0/1/2_i` | 子代理 B |
| 3 | `rtl/w3a/ctrl_key_map.v` | 新增 `lock_toggle_req_o`（**键位待定**：建议 `行2列1`/idx 9，现为"效果器占位"） | 子代理 B |
| 4 | `rtl/w3a/led_indicator.v` | 档 2 语义改"音量颤音"；新增"锁定 = 快闪"（复用现有 `BL_FAST`，⛔ 不新做呼吸） | 子代理 B |
| 5 | `tb/w3a/tb_fader_gear.sv` | 判据重写（§六） | 子代理 C |
| 6 | `constr/top.sdc` | `set_max_delay 16.4 → 18.0` | 子代理 D |
| 7 | 文档 | 手册 §2/§4 + 屏方案 §〇之二 同步 | 子代理 D |

⚠️ **文件所有权严格分离**（项目红线：`rtl/` 不允许两个代理同时改）：
- A 独占 `rtl/w3a/fader_gear.v`
- B 独占 `rtl/top.v` + `rtl/w3a/ctrl_key_map.v` + `rtl/w3a/led_indicator.v`
- C 独占 `tb/w3a/tb_fader_gear.sv`
- D 独占 `constr/top.sdc` + 文档
- ⛔ 谁都不许碰 `rtl/w3a/async_pluck_capture.v`（别人的 WIP）

⚠️ **B 依赖 A 的端口**，所以 §4.1 的接口**必须先定死**（本文已定），B 按本文写即可，⛔ 不要等 A 完成。

---

## 六、判据（⭐ 每条都要能红）

### 6.1 `tb_fader_gear.sv` 重写

| 组 | 判据 | 期望 |
|---|---|---|
| A | 复位后 `gear_o == 1`、**`hold_o == 3'b000`（全解锁）**、`transpose_semi_o == 0`、四个颤音输出全 0 | 新增 |
| B | `'J'` 连按三次：1→2→0→1（三档循环闭合） | 改（原为 0⇄1） |
| C | `gear_sel2_i` 单脉冲 ⇒ 直接到档 2（不经过 0/1） | 新增 |
| D | 档 2 且 `!hold[2]`：`trem_depth_o == ch2_i`、`trem_rate_o == ch3_i` | 新增 |
| E | 档 2 且 `!hold[2]`：`vibrato_*` **保持**（⛔ 不为 0） | 改（原为"==0"） |
| F | 档 1 且 `!hold[1]`：`vibrato_* == ch2_i/ch3_i`（逐位）；`trem_*` 保持 | 改 |
| G | 档 0 且 `!hold[0]`：`transpose_semi_o` 跟随差分；两个颤音**都保持** | 改（原为"全 0"） |
| H | 档 0 且 `hold[0]`：推子跨半音边界 ⇒ `transpose_semi_o` **不变** | 新增（L3） |
| I | `lock_toggle_i` 翻转的是**当前档**的位，且只翻一位 | 新增 |
| J | ⭐ **共存判据**：档 1 把 ch2 推到 0x800 ⇒ 锁 ⇒ 切档 2 把 ch3 推到 0x400 ⇒ 锁 ⇒ 切回档 1 ⇒ `vibrato_depth_o` 仍 0x800 **且** `trem_rate_o` 仍 0x400 | 新增（核心） |
| K | 档 0 的"进档接管"在 `hold[0]==1` 时不发生 | 新增（L3） |
| L | 复位后 `hold_o == 3'b000`（全解锁）；若两推子都在 0 ⇒ 三档输出全 0（上电静默） | 新增（L4） |

### 6.2 其它

| 判据 | 命令 | 期望 |
|---|---|---|
| `tb_led_indicator` | 逐位比 24 位颜色 | 档 2 = 黄、锁定 = 快闪，期望同步 |
| `tb_top_ctrl_wire` | 现有 | 不变（八度那条已改过） |
| `tb_ctrl_key_map` | 现有 + 新增锁定键 | 锁定键恰好一次、不串扰 |
| 综合 | `sim/gowin_build.ps1` | **无 ERROR**（EX2000 多驱动、PA2122 都要盯） |
| 时序 | P0-30 门 | 真实 slack ≥ 0 |

---

## 七、子代理分工（4 路并行）

| 路 | 任务 | 独占文件 | 产出 |
|---|---|---|---|
| **A** | `fader_gear.v` 改造 | `rtl/w3a/fader_gear.v` | 改完 + 自检（编译） |
| **B** | `top.v` 接线 + `ctrl_key_map` 锁定键 + `led_indicator` 档 2/锁定显示 | `rtl/top.v`、`rtl/w3a/ctrl_key_map.v`、`rtl/w3a/led_indicator.v` | 改完 + 自检 |
| **C** | `tb_fader_gear.sv` 判据重写 | `tb/w3a/tb_fader_gear.sv` | 改完 + 跑通 |
| **D** | `top.sdc` 16.4→18.0 + 文档同步（手册/屏方案） | `constr/top.sdc` + 文档 | 改完 |

⚠️ **并行约束**：
- 四路**文件不重叠**，可以同时开工
- ⛔ 都不许跑 PnR / 全量回归（PnR 只能由父代理在四路都完成后跑一次）
- ⛔ 都不许 `git add/commit`
- C 的 tb 依赖 A 的端口，**按本文 §4.1 的接口写**，⛔ 不等 A

---

## 八、落地顺序

```
① 四路子代理并行改（A/B/C/D）
② 父代理汇总：编译全 RTL（-s top）+ 跑 tb_fader_gear / tb_led_indicator / tb_ctrl_key_map / tb_top_ctrl_wire
③ 全部绿 ⇒ 跑一次 PnR（同时验 B 的 18.0 和本改动）
④ PnR 绿 ⇒ 归档位流 + 更新手册 + 本地 commit（⛔ 不推，等下次一起压）
```

---

## 九、用户已确认（2026-10-18）

| # | 问题 | 裁定 |
|---|---|---|
| **Q1** | 上电默认锁定状态 | ⭐ **全解锁**（`hold_o` 复位 = `3'b000`） |
| **Q2** | 锁定键用 `行2列1`（idx 9） | ✅ **是**。用户原话："效果器已经不需要了" ⇒ idx 9 从"效果器占位"改为**锁定键** |
| **Q3** | 锁定显示 | ✅ **快闪**（复用现有 `BL_FAST`） |

**额外要求**：手册与对应文档必须同步改（用户原话："记得改手册和对应的文档"）。
