hokuu1102/Gowin2026-PolySynth/bringup/33-上机手册-20261016-夜.md

# 上机手册（第 6 版）—— 🔴 键盘回归修复 + 滑音链时序 + 上行鼓标记（2026-10-16 夜）

> **码流**：`impl/pnr/Gowin2026.fs`（归档副本 `build/bitstreams/20261016-220458-v3-cstfix.fs`）
> **sha256**：`316FE958A45C4A8C2F4D29D285783E742F48E1DEA315953341796B9EB3F7AE80`
> **大小/时间**：19.7 MB · 2026-10-16 22:04:58
> **代码**：`main` 提交 **`b0cac597`**（已推送 `origin/main`）⇒ ⭐ 队友拉下来重跑能得同一版
> **时序**：**63 setup / 0 hold** · `clk_sys` Fmax **56.482 MHz**（约束 50 ⇒ 余量 +13%）
> **资源**：Logic 44907(75%) · **CLS 26627(89%)** · BSRAM 103/118(88%) · Register 22432(37%)
> **构建门**：全过 · exit 0（NL0002 ✓ · EX3793 ✓ · P0-25 hold 0.166 ns ✓ · P0-23 ✓ · P0-26 ✓ · P0-29 ✓ · BOM ✓）

> ⚠️ **与第 5 版的关系**：第 5 版（`7ADC69B3…`，15:51，0/0）之后，`constr/top.cst` 被做了一次
> **A/B 实验**（把 `h5_scope` 的 `GROUP`/`GRP_LOC` 注掉）且**从未回退** ⇒ 🔴 **键盘静音 + 持续杂音**。
> 本版把那条约束**恢复**，键盘已上板实测恢复 ✅

---

## 〇、先做三件事（不做这三件，后面测了也不可信）

### 1. 校验 sha256

```
316FE958A45C4A8C2F4D29D285783E742F48E1DEA315953341796B9EB3F7AE80
19.7 MB · 2026-10-16 22:04:58
```

### 2. 接线接 **J9**，不是 J10

```
ADC      N1/N2（sclk/mosi）· N3/N4（左手板1）· N5/N6（左手板2）· N7/N8（右手板）
电源     N11 = +5V · N12 = GND
按键灯   N17/N18/N19（le/sdi/clk）· N20/N21（oe_n[0]/[1]）
调试串口 N25 = uart_tx · N26 = uart_rx
```

### 3. 串口参数

```
波特率 500000 8N1（⛔ 不是 115200）· 交叉接线 · 共地
测通用 'P'（读 pos，会回包）；'T' 不回包
```

---

## 一、上电三看（10 秒判状态）

| 看什么 | 正常 | 异常 |
|---|---|---|
| 心跳灯 | 摇杆中位**常亮**；拨动时**闪** | 完全不动 = 时钟/配置问题，量 V22，用旧位流复烧对比 |
| 心跳灯快闪 | 中位且有故障时快闪 | 一直快闪 = 有故障被锁存 |
| 开机自检和弦 | 复位后自动响约 1 秒 | 不响 = 音频链或时钟问题 |

**心跳灯三态**：中位常亮 · 有故障快闪 · 离位照常闪。**拨弦时会灭一下**——那一下就是"这一拨被采到"的现场证据。

### ⭐ 本版新增：键盘回归的 1 秒自检

**按一下键盘/指板，有没有声音。** 这是本版修复的核心症状。
（症状曾表现为：**按了没声** + **持续"滋滋滋"**，而**灌谱正常**。）

---

## 二、🔴 本版修了什么（11 条，逐条带证据）

### 🔴 1. 上板回归：键盘无声 + 持续杂音 —— 根因是**约束，⛔ 不是 RTL**

| | |
|---|---|
| **根因** | `constr/top.cst` 把 `GROUP h5_scope` / `GRP_LOC h5_scope R[1:44]C[1:148]` **整条注释掉**（10-16 的 A/B 实验），**从未回退** |
| **为什么键盘死、灌谱活** | 键盘是**物理扫描型**（行列矩阵 + ADC + 消抖 + 时钟偏斜）⇒ 对布局敏感；灌谱是 **UART 喂的数字流** ⇒ 鲁棒。日志有 `PR1014 ... 'clk_d' ... excessive delay or skew` |
| **证据** | 同一次 PnR：setup 违例 **0 → 226** · `clk_sys` Fmax **61.071 → 55.571 MHz** · `Logic Level` 19 → 9 |
| **修法** | 把两行约束**恢复**（`constr/top.cst` 与 HEAD 逐字一致） |
| **修后** | 违例 **226 → 63** · Fmax **55.571 → 56.482 MHz** · 🔴 **上板键盘恢复** ✅ |
| **教训** | ⚠️ 交接文档曾写"已回退" —— **实际没有**。⭐ 纪律：**A/B 实验要么跑完落盘结论、要么当场回退，⛔ 不留中间态** |

### 🔴 2. 滑音判定链 **67 级 → 9 级**（时序）

```
改前：Logic Level 67 · Fmax 15.052 MHz · 304 条 setup 违例
      （最差 slack −50.033 ns，比 20 ns 周期还长 2.5 倍）
根因：滑音 B 的选法从"第一个形成就 break"改成"行程最大的同排邻居"
      ⇒ 16 次迭代、第 k 次依赖第 k−1 次 ⇒ 综合成 16 级串联 12 位比较器
修法：① 16 级串联链 → 4 级两两合并树
      ② 再 → 2 邻居直选（⭐ 关键洞察：候选最多 2 个，⛔ 不需要 16 路 argmax）
      ③ `is_h_adj(A,si)` → 16 位邻居掩码查表（干掉 384 个比较器）
结果：Logic Level 67 → 33 → 21 · 综合 Fmax 19.505 → 40.503 → 50.365 MHz
```

### 🔴 3. `left_ax_n` 取【最大】轴号的**语义回归**（真 bug）

```verilog
原循环丢了 `!left_hit` 短路 ⇒ 每个命中都覆盖 ⇒ 取【最大】轴号
而 HEAD 与 event_extract.v:328 的注释都是【最小】⇒ 语义回归
⇒ 同帧 ≥2 个轴离开时，滑音的 A 取错、B 配对集错、方向错
⚠️ 为什么仿真全绿：旧判据每次只驱动【一个】负 delta 轴 ⇒ 多轴同帧从未被测
✅ 新判据 tb/w3a/tb_ee_multileave.sv（改前必红 · 非空洞控制为绿）
```

### 🔴 4. 上行帧 `byte[7][3:0]` 鼓标记**只覆盖灌谱鼓**

| 来路 | 改前 `[3:0]` | 后果 |
|---|---|---|
| 灌谱鼓 | ✅ `drum_type` | 正常 |
| **键盘打鼓** | 🔴 **0** | ESP32 解成**旋律**（而 `[5:4]` 那时是 drum_type）|
| **内部鼓机** | 🔴 **上次 pop 的陈旧值** | 可能取到 4..15 越界值 |

```
修法：top.v 新增 `up_drum_mark_w` —— 三路鼓统一按 `mg_evt_axis[1:0]` 反推 drum_type
      （⭐ 三路鼓的轴号都等于 12 + drum_type）
      ⭐ 全程只用 evt_merge 下游信号 ⇒ 结构上不可能成环
      ⛔ 不再 OR 上 `sa_up_axis`（它是寄存器、对源 B/C 事件是陈旧值）
判据：tb/top/tb_top_upstream_timbre.sv 补"键盘打鼓 Snare ⇒ byte[7] = 0x11"
```

### 5. 鼓与旋律彻底分离（第 5 版起的核心）

```
鼓轴三路统一 12/13/14/15（一件一轴）：内部鼓机 · 键盘打鼓 · 灌谱
src 统一 SRC_KDRUM(5) · 鼓 inc 统一从 rtl/w3c/drum_inc_defs.vh 取（单一来源）
⇒ 同一件鼓在三路落同一个 (axis, src) ⇒ 互相重触发、不叠 voice
⇒ 四件鼓能【同时】响（原来四件共用轴 15 ⇒ 同时只能响一件）
```

### 6. LED 指引根治"挂灯"

```
guide_lamp 新增 stream_alive_i + 参数化 TIMEOUT_CLKS（默认 1 秒）
top.v: .stream_alive_i (eb_rd_valid | ps_note_valid)
⇒ "停播即清"：流停了 1 秒清 guide_key_o
⭐ 触发源刻意【不是】"多久没有 note 事件"——真曲实测最长休止 28 秒
```

### 7. 滑音阈值与 B 的选法（产品裁定）

```
SLIDE_START_TH 64 -> 4（逐帧增量语义，64 码快甩也到不了）
B 的选法："第一个形成的" -> "行程最大的同排邻居"
⚠️ 有意的产品裁定，5 个可达组合的行为会变（见 §四 滑音）
```

### 8. `inc` 第三份硬编码表消掉

```
top.v 原来又抄了一遍 4 个 phase_inc 字面量（且件序与 drum_gen 不同）
⇒ 任一侧重排就静默换音色
✅ 现在改为 include rtl/w3c/drum_inc_defs.vh（与 drum_gen / seq_arb 同一份）
```

### 9. LED 查表从"160 位变步长部分选择"改成 `case`

```
原实现综合成桶形移位器（约 1300 LUT）⇒ 是布线拥塞的元凶之一
改成 case 后网表实测约 20 个 LUT4（16:1 mux 树）
```

### 10. `guard` 补 `Map_Option`

```
sim/gowin_build.ps1 原来只挡 Place_Option / Route_Option，漏了第三个算法选项 Map_Option
（set_option -tm）⇒ 它会一直生效且静默
✅ 现在三个一起钉（Map/Place/Route 必须全 0）
```

### 11. 新增 `tools/check_static.ps1`（7 道静态门一条命令）

```
A1 HDL 无 BOM · A2 .ps1 编码 · A3 P0-23 异步复位 · A4 P0-29 观测线(14 条)
A5 .gprj 注册 · A6 PnR 算法选项 0/0/0 · A7 .gprj 注释无裸 '--'
⇒ 原先 A1 排在 PnR 跑完之后、A2 压根没接 ⇒ 要等 10 分钟才发现
用法：powershell -NoProfile -ExecutionPolicy Bypass -File tools\check_static.ps1
```

---

## 三、必测（按优先级）

### ⭐ A0. 键盘 / 指板 —— **本版修复的核心，先测这条**

```
1. 按键盘 16 键 ⇒ 每个键都要出声
2. 按指板 16 品 ⇒ 每个品都要出声
3. ⛔ 不应再有"按了没声"
4. ⛔ 不应再有持续"滋滋滋"（背景噪声）
```
**判据**：本版把 `h5_scope` 约束恢复了。若这条不过，说明**不是**约束问题，需要切下一刀
（独立 worktree 出 `af9f2cdb` 对比）。

### A1. 内部鼓机（源 B）—— **能同时响多件**

```
触发：键 0（源 B 开关：鼓机/节拍器）+ 键 8（鼓机节奏型）
1. 四件鼓是否【同时响】（原来四件共用轴 15，同一时刻只能响一件）
2. 四件音色：底鼓 60Hz · 军鼓 480Hz · 踩镲 1920Hz · 嗵鼓 200Hz
3. 正常 funk 鼓型：底鼓 1/3 · 军鼓 2/4 · 踩镲八分 ⇒ 不缺件
4. 节奏型切换（键 8）是否跟着换
```
⚠️ **上电默认是【关】**（`met_on_r` 复位=0）⇒ 要按开才有。

### A2. 键盘打鼓

```
触发：串口 'K' 或对应键 ⇒ 灯带"键盘打鼓"灯亮
1. 四件鼓垫各响各的（⛔ 不应全变成踩镲）
2. 松手能停（⛔ 不应挂音）
3. ⭐ 本版新增：**上行帧 `[3:0]` 应带上 drum_type**（ESP32 侧可查）
```

### A3. LED 指引（改动最大）

```
1. 灌谱播放 ⇒ LED 跟着音高走
2. 停播 1 秒 ⇒ 灯自动清（⛔ 不应挂住）
3. 复位后不闪（原来会闪）
```

### A4. 鼓与旋律彻底分离

```
1. 键盘弹旋律 + 灌谱鼓 ⇒ 互不干扰
2. 同一件鼓在三路（鼓机/键盘鼓/灌谱）落同一个 (axis, src)
```

### A5. 键 14 = 一键恢复默认音高

### A6. 指板一次拨弦出和弦（A 方案）

---

## 四、⚠️ 已知问题（⛔ 不要用这版判这些）

| # | 问题 | 说明 |
|---|---|---|
| **1** | 🔴 **仍有 63 条 setup 违例**（HEAD 是 0）| 最差路径落点：`u_event_extract`(12/25) · `u_calib0`(8) · `u_vibrato_lfo`(4)。⚠️ **不是"干净的绿色交付点"**，只是比今晚那版好得多 |
| **2** | 🔴 **CLS 26627/29952 = 89%** | 接近天花板（本项目 CLS 89% 时布线耗时 15~26 分钟）|
| **3** | 🔴 **`RESERVED_N = 5` 鼓池超订** | 鼓机 4 件（永不释放，`drum_gen` 只发 note_on）+ 键盘打鼓 ⇒ 挤。⚠️ 不影响旋律（旋律走 27 路普通池）|
| **4** | ⚠️ **滑音 `SLIDE_START_TH = 4`** | 阈值极低 ⇒ 一开滑音就是 2 kHz 帧率的事件流（持续音高抖动）。默认关（要按 `'W'` 且切指板模式）|
| **5** | ⚠️ `top.v:2779` 的账已过时 | 仍写"节拍器 1 + 鼓机 1（共用轴号）⇒ 需要 2"，实际已是四轴 |
| **6** | ⚠️ `sa_up_axis` 现为死线 | `top.v:6149` 已改用 `up_drum_mark_w` ⇒ `seq_arb.evt_up_axis_o` 与它的复位修复是死代码（综合会剪掉）|
| **7** | ⚠️ `guide_lamp` 的 `stream_timeout` 会**粘住** | 与注释"单拍脉冲"不符；无害（只清 LED 位图）|

---

## 五、退路（⛔ 别丢）

```
已知可用（键盘好的那版）：
  evidence\fx_splitcone_20261015\Gowin2026_splitcone_61.1MHz.fs
  sha256 5F07A2048FA0821E00C2CD29B1B3F951B7C8BB2B80327E765164E883BF3B0914
  0 setup / 0 hold · Fmax 61.067 MHz · 回归 204/204
  ⚠️ 它早于 10-15 21:07 ⇒ 缺"10-15 那一晚 + 10-16 一整天"的全部改动
     （鼓机方案B / P0-4 拨弦修复 / 延迟 mix 律 / 失真 ×256 / 键14 / 指板和弦
      / 三个挂音修复 / 本轮全部）⇒ 只能当"键盘好的兜底"，⛔ 不是"功能基线"
```

### 🔴 重建之前**必须先归档**（本版新增工具）

```powershell
# sim/gowin_build.ps1 每次启动会 Remove-Item impl/pnr -Recurse -Force
# ⇒ 上一版的 .fs 会被删掉，而 impl/ 是 git-ignored ⇒ git 也救不回来
powershell -NoProfile -ExecutionPolicy Bypass -File tools\archive_bitstream.ps1 `
    -Label <标签> -Note "<说明>"
# ⇒ build\bitstreams\<时间戳>-<标签>.fs ＋ 追加 sha256 到 sim\evidence\bitstream-index.md
```

---

## 六、出问题请记四项

```
1. 症状（看到/听到什么）+ 什么操作之后
2. sha256（确认烧的是哪版）
3. 串口打印（500000 8N1）
4. 灯带状态（哪几颗灯亮）
```
