hokuu1102/Gowin2026-PolySynth/bringup/30-上机指南-20261016.md

# 上机手册（第 5 版）—— 鼓分轴 + LED 跟音高 + 鼓轴统一（2026-10-16 15:5x）

> 码流：`impl/pnr/Gowin2026.fs`
> sha256：`7ADC69B3127C7C5EC56A43F2F9CCB905853E1A3B0FC8AE81FF32ECD2FB55AEE7`
> 大小：19.8 MB · 生成：2026-10-16 15:51:40
> 时序：**0 setup / 0 hold** · 零 ERROR / 零多驱动 / 零未布通
> 资源：Logic 44185(74%) · CLS 26495(89%) · BSRAM 103/118(88%) · DSP 30.5
> 判据：`drum 7/7 · seq_arb 1/1 · guide 3/3 · led 3/3 · key_drum 1/1 · note_manager 5/5`

---

## 〇、先做三件事（不做这三件，后面测了也不可信）

### 1. 校验 sha256

```
7ADC69B3127C7C5EC56A43F2F9CCB905853E1A3B0FC8AE81FF32ECD2FB55AEE7
19.8 MB · 2026-10-16 15:51:40
```

### 2. 接线接 **J9**，不是 J10

```
ADC      N1/N2（sclk/mosi）· N3/N4（左手板1）· N5/N6（左手板2）· N7/N8（右手板）
电源     N11 = +5V · N12 = GND
按键灯   N17/N18/N19（le/sdi/clk）· N20/N21（oe_n[0]/[1]）
调试串口 N25 = uart_tx · N26 = uart_rx
```

### 3. 串口参数

```
波特率 500000 8N1（不是 115200）· 交叉接线 · 共地
测通用 'P'（读 pos，会回包）；'T' 不回包
```

---

## 一、上电三看（10 秒判状态）

| 看什么 | 正常 | 异常 |
|---|---|---|
| 心跳灯 | 摇杆中位**常亮**；拨动时**闪** | 完全不动 = 时钟/配置问题，量 V22，用旧位流复烧对比 |
| 心跳灯快闪 | 中位且有故障时快闪 | 一直快闪 = 有故障被锁存 |
| 开机自检和弦 | 复位后自动响约 1 秒 | 不响 = 音频链或时钟问题 |

**心跳灯这版是三态**：中位常亮（=摇杆在中位）· 有故障快闪 · 离位照常闪。**拨弦时会灭一下**——那一下就是"这一拨被采到"的现场证据。

---

## 二、本轮必测（按优先级）

### A1. 内部鼓机（源 B）—— ⭐ 本轮核心修复：**能同时响多件了**

```
触发：键 0（源 B 开关：鼓机/节拍器）+ 键 8（鼓机节奏型）
```

**要测什么**

```
1. 四件鼓是否【同时响】（原来四件共用轴 15，同一时刻只能响一件）
2. 四件音色：底鼓 60Hz · 军鼓 480Hz · 踩镲 1920Hz · 嗵鼓 200Hz
3. 正常 funk 鼓型：底鼓 1/3 · 军鼓 2/4 · 踩镲八分 => 不缺件
4. 节奏型切换（键 8）是否跟着换
```

**判据**：改之前内部鼓机四件挤一个轴 ⇒ 互相抢 voice ⇒ **同时只能响一件**。改之后四件分轴 12/13/14/15，各自独立。

### A2. 键盘打鼓

```
触发：键 4（键盘打鼓开关）
```

```
1. 四件鼓各占一个键区（sel = src_a_axis[3:2]）
   按不同位置出不同鼓
2. 力度：max(键盘力度, 本件基础力度) => 轻敲也够响
3. 与 A1 对比：同一件鼓（如同为底鼓）在 A1 与 A2 下
   应该落在【同一个轴】=> 互相重触发，不叠成两个 voice
```

### A3. LED 指引（⭐ 本轮改动最大）

```
触发：灌谱后自动（或键 3 切显示模式看 HDMI 上的引导）
```

**⚠️ 重要预期**：LED 点亮现在**靠帧里 bits[4:0] 的 `note_off5`**（= MIDI 音高 − 45）。ESP32 侧**还没填这个字段**（现有 hex 那 5 位是 0），所以：

```
✅ 上板时 LED 很可能是【全暗】—— 这是已知的过渡状态，不是 bug
   旧的 hex：offset 0 = A2 => 查表是哨兵 => 不点灯
✅ 一旦 ESP32 填上 note_off5，灯会跟着音高走（同轨不同音高 => 不同灯）
```

**这条是"两边必须一起上"的第三处**。如果测到全暗，请确认 ESP32 的 `score_word.py` 是否已填 `note_off5`。

### A4. 鼓与旋律彻底分离

```
1. 灌一份含鼓轨的谱 => 鼓必须是鼓的发声（不是电子音）
2. 旋律轨绝不能变成鼓（结构保证，与轴号无关）
3. ⚠️ 镲片（46/49/51/52/53/55/57/59）目前【全部按 HiHat 发声】
   —— 这是本轮裁定的映射，别当成 bug
```

### A5. 键 14 = 一键恢复默认音高

```
1. 按变调升（键 6）几次，确认变了
2. 按键 14（列2行3）=> 变调回 0
3. 换一个偏移再来一次
```

### A6. 指板一次拨弦出和弦

```
1. 按住 2 个品，拨一次 => 两个音都响
2. 按住 3 个品，拨一次 => 三个音都响
3. 按 1 个品 => 仍只响 1 个（边界，别改过头）
4. 拨弦后松其中一品 => 只放掉那个音，其余继续
```

---

## 三、滑音（⭐ 触发条件很具体，先按这个试）

### 三个开关/模式前提

```
1. 滑音开关：键 2（必须开）
2. 模式：指板模式（键 7 或串口 'A'）
3. 硬件布局：【水平相邻】的 12 对（霍尔键位表，不是轴号相邻）
```

### 触发手势（三个条件同时满足）

```
① 水平相邻：A 和 B 必须是邻居表里的水平邻居
② 一减一增：
   · A 侧行程【减少】超过 8 码（dA < −8）
   · B 侧行程【增加】超过 64 码（dB > +64）
③ 时间窗口：A 离开后 1000 帧内（约 500 ms）B 要形成
```

### 你反馈"难触发、听不出" —— 手册里如实记录

```
可能原因（按排查优先级）：
1. 水平邻居关系不对 —— 请在 A 上按住，试【左右】邻居而不是任意两个
2. B 侧增量不够 —— 若按 A 时手已压到 B 边缘，从 A 移到 B 时增量可能很小
   => 试"更大幅度地滑过去"，或确认 B 是从零开始形成
3. 时间窗口 —— 从 A 离开到 B 越阈要在半秒内完成
4. 开关没开 —— 键 2 在指板模式下必须开
```

### ⚠️ 已知限制与"设计如此"的行为（⛔ 不是 bug）

```
1. 邻居表"同排相邻"：
   上排左：6-7-0-1     下排左：5-4-3-2
   上排右：14-15-8-9   下排右：13-12-11-10
   => ⛔ 跨排不算滑音（上排甩到下排）
   => ⛔ 跨板不算滑音（右手甩到左手）

2. ⭐⭐ "甩过多个键"时，滑音目标 = 行程最大的那个邻居
   —— 这是【有意的产品裁定】，不是 bug：
     本项目裁定"滑音模式开着 ⇒ 相邻先后发生就算滑音"，
     而"取行程最大"让 B 持续跟到【最终停下的那个键】，
     中间不会断成多段滑音（否则音高一跳一跳）。
   => 所以：快速从左甩到右时，滑音【一路跟到最右】而不是分段跳
   => ⚠️ 若你觉得"甩过两个键时音高/方向不对"，这是设计如此，
     ⛔ 不要当 bug 报；应在 slide_position_ctrl / 标定层看插值

3. 实际物理上，每个键的【同排邻居最多 2 个】（不是 4 个）
   =>"取最大"的搜索深度 ≤2（比预估更省）
```

---

## 四、效果器串口命令（速查）

### 帧格式与三条硬规则

```
71 <变量号> <值> FF FF FF
1. 值不能是 0xFF（帧尾）=> 最大 254
2. 值只有一个字节 => 增益只能表达 128 的整数倍（精确值用 gain-raw）
3. 上电 mask=0 => 效果器全旁路，必须先发 0x10
```

### 变量表

| 变量 | 名字 | 换算 | 默认 |
|---|---|---|---|
| `0x10` | mask | bit0=失真 bit1=合唱 bit2=延迟，bit4 空闲 | 0（全关） |
| `0x11` | gain | 值/16（64=4.0× · 254=15.875×） | 64 |
| `0x12` | trim | 值/128（32=0.25× · 128=1.0×） | 32 |
| `0x13` | mix | Q0.8，加湿量 | 128 |
| `0x14` | fb | Q0.8，延迟专用 | 96 |
| `0x15` | depth | 音量颤音深度（0=听不出） | **0** |
| `0x16` | rate | 音量颤音速率 | 7 |
| `0x17` | dlylen | 值×128 采样（64=168ms · 200 饱和到 333ms） | 64 |
| `0x18` | chorlen | 值×32 采样（23=15ms） | 23 |

### 最常用的十几条

```
71 10 00 FF FF FF     全关
71 10 01 FF FF FF     只失真
71 10 02 FF FF FF     只合唱
71 10 04 FF FF FF     只延迟
71 10 07 FF FF FF     全开（注意是 07 不是 17）

71 11 80 FF FF FF     gain=128 => 8.0×（要削顶至少要 8 倍）
71 11 C0 FF FF FF     gain=192 => 12.0×
71 11 FE FF FF FF     gain=254 => 15.875×
71 12 20 FF FF FF     trim=32 => 0.25×（默认）=> 净增益 1.0

71 17 40 FF FF FF     延迟 168 ms
71 17 C8 FF FF FF     延迟 333 ms
71 14 00 FF FF FF     反馈 0 => 只回一声
71 18 17 FF FF FF     合唱 15 ms
71 15 60 FF FF FF     ⭐ 音量颤音深度 96（默认 0，不发就听不出）
71 16 20 FF FF FF     颤音速率 32
```

### 用工具（省得手打）

```bash
python tools/fx_ctrl.py --port COMxx on / off / mask 0x01 / gain 128 / trim 128
python tools/fx_ctrl.py --port COMxx drive 200    # 驱动拉高，音量自动不变
python tools/fx_ctrl.py --port COMxx sweep        # 增益扫描
```

### 三个容易搞错的口径

```
1. 净增益 = gain × trim。默认 (64,32)=1.0。旧字节值 (128,64) 现在 = 4.0（响 12dB）
2. 全开 = 0x07，不是 0x17（bit4 是空转位）
3. 音量颤音 depth 默认 0（数值恒等）—— 不发 71 15 就听不出颤音
```

### 失真为什么听不出（你的实测已确认）

```
你实测输入约 1/8 FS，默认 gain 4.0× => 0.5 FS => 到不了削顶阈值
要削顶至少 gain 8.0×（71 11 80），推荐 12~15.9×
失谐导致削顶只在拍峰附近 => 间歇性破音 => 这是已知特性
```

---

## 五、整机回归（确认没弄坏别的）

```
1. 上电什么都不开 => 听起来和以前一样（零回归）
2. 16 键逐个按：节拍器/音色/滑音/显示/键盘打鼓/推子档/变调升/模式/
   节奏型/占位/变调降/TestMode/looper清空(长按2s)/备用/音高归零/标定
3. looper：录 -> 放 -> 清空
4. HDMI 三种显示模式
5. 推子：颤音深度、实时变调
```

---

## 六、已知坑

```
1. 接线是 J9，不是 J10
2. 串口 500000 8N1，不是 115200
3. 'T' 不回包，测串口通不通用 'P'
4. 上电 mask=0 => 效果器全旁路
5. 默认档 (64, 32)，不是 (128, 64)
6. LED 在 ESP32 填 note_off5 之前【全暗】（过渡状态）
7. 镲片全部按 HiHat 发声（本轮裁定，不是 bug）
8. 鼓的 inc 由 FPGA 从共享表取（灌谱与键盘打鼓必然一致）
```

---

## 七、出问题请记四项

```
1. 现象（听到/看到什么）
2. 当时发了哪些帧（完整 HEX）
3. 是否复位后可复现
4. 心跳灯状态（常亮 / 慢闪 / 快闪）
```

第 4 项特别有用：它是判断"故障被锁存"还是"运行中出错"的最快依据。
