hokuu1102/Gowin2026-PolySynth/bringup/16-上板操作手册-20260929.md

# 📖 上板操作手册（⭐ 2026-09-29 版 · **唯一照做版**）

> ## 🔴🔴 **2026-09-29 下午【重大更新】—— 上板实测已抓到 3 个 bug 并修好**
>
> | ⭐ bug | ⭐ 现象 | ⭐ 根因 | ⭐ 状态 |
> |---|---|---|---|
> | **①** | ⭐ loop 回放中按 `C` ⇒ **挂音不停** | 🔴 `looper` 的 `clear` **不补发 `note_off`** | ✅ **已修** |
> | **②** | ⭐ 按到底出现**"电子音"**（⭐ 音色变、⭐ 幅度趋势不变） | 🔴 **位置式力度同时改了【音色】** —— ⭐ `oscillator_bank` 按 `vel` 在 **正弦 ↔ 三角** 之间插值 ⇒ ⭐ 按到底 = **纯三角波**<br>⭐ **实测谱形**（100 ms / 100 kHz）：⭐ h3 = **−18.9 dB**（三角波理论 **1/9 = −19.1 dB**）· ⭐ h4 = **−46.5 dB** 深零点 ⇒ ⭐ **就是三角波** ✅ | ✅ **已修**（⭐ 力度不再参与音色） |
> | **③** | ⭐ `probe_q.py` **收不到 `Q` 包** | ⭐ **不是 bug** —— ⭐ `DPOS_DIAG = 0` 的**编译期门控** | ✅ **已改 1** ⇒ ⭐ **`Q` 包现在会回** ✅ |
>
> ⭐⭐ **⇒ 下面"铁律 2"已经变了**（⭐ 见 §〇）✅
> ⭐⭐ **⇒ 请按 §十一 的"复测清单"重新上板一次** ✅

> **用途**：⭐ **从"电脑前"到"测完收工"一条龙** —— ⭐ 每步都有**预期现象**，⛔ 现象不符就停下。
> **取代关系**：⭐ **本手册取代** `bringup/10-上板操作卡-20260924.md` 与 `bringup/15-上机-90分钟最高效率-20260926.md`
> （⭐ 那两份仍可作**深挖**用，⚠️ 但**有两处口径已过时** ⇒ ⭐ 见下方"四条铁律"第 1、2 条）。
> **本版 `.fs`**：⭐ `impl/pnr/Gowin2026.fs`（⭐ **含 bug①②③ 的修复** ⇒ ⭐ 时间戳见 §一）
> ⭐ **归档副本**：`build/bitstreams/`（⭐ 每次 PnR 后归档 ✅）

---

## 〇、🔴🔴 先看这四条（⛔ 不看会白忙）

| # | ⭐ 事项 | ⚠️ 为什么 |
|---|---|---|
| **1** | 🔴 **串口波特率 = `500000`**（⭐ 8N1、⛔ 无流控） | ⚠️ **旧操作卡写的是 `1000000`** ⇒ 🔴 **照它做会收到【乱码】，而且不报错** ✅<br>📌 依据：`top.v` 里 `uart_rx.BAUD_DIV=100` ＋ `calib_cmd.BAUD=500_000` ＋ `uart_tx.BAUD_DIV=100`（⭐ 50 MHz ÷ 100 = **500 kbps，整除无误差**）✅ |
| **2** | 🔴 **【2026-10-01 更正：本条已过时】** ⭐ 原写"`'Q'` 诊断已【打开】（`DPOS_DIAG = 1`）⇒ 包会回" | ⚠️ **实际 `DPOS_DIAG = 0`**（`rtl/top.v:185`）⇒ ⭐ **`Q<轴><dpos>` 包【不会回】**；⭐ 要它需改 1 **重跑 PnR**（⭐ 与 `bringup/18:96` · `21:91` 一致） |
| **3** | ⚠️ **`RAW_MEDIAN_EN = 0`**（中值滤波**关**） | ⭐ 本版**没有**开 `raw` 中值滤波 ⇒ ⭐ **`raw` 的跳变会原样传下来** —— ⭐ 这正是本次要**测**的东西（⛔ 不是故障）✅ |
| **4** | 🔴 **【2026-10-01 更正：本条已过时】** ⭐ 原写"`SEL_DRUM = 0`（源 B = 节拍器）⇒ 听不到鼓机" | ⚠️ **现值 `SEL_DRUM = 1`**（`rtl/top.v:120`）⇒ ⭐ **当前位流是【鼓机】档，节拍器不响**（⭐ 反过来）；⭐ 且 `'B'` 是"源 B 开关" ⇒ 现在它开的是**鼓机** |

---

## 〇bis、⭐⭐ 2026-09-30 更新（⭐ 与本文其余部分冲突时，⭐ 以此为准）

| ⭐ # | ⭐ 项 | ⭐ 现在的口径 |
|---|---|---|
| ⭐ 1 | ⭐ **S2（`AB13`）不再是节拍器** | ⭐ **S2 = 音色切换键** ✅（⭐ BASS→GUITAR→PIANO→PAD 循环 ✅）—— ⚠️ 本文"阶梯 5 · 按 `AB13` 开节拍器"**已作废** ✅ |
| ⭐ 2 | ⭐ **节拍器改走串口** | ⭐ 发 **`'B'`** 开 / 关 ✅（⭐ 开时**从强拍起** ✅） |
| ⭐ 3 | ⭐ **新增串口 `'D'`** | ⭐ **鼓机节奏型切下一个**（⭐ 0→1→2→3→0 ✅）—— ⚠️ **只在 `SEL_DRUM=1` 的 bitstream 里有意义** ✅ |
| ⭐ 4 | ⭐ **四种音色已实装** | ⭐ ⚠️ 本文"只有单音色"**已作废** ✅（⭐ AKWF 四音色 ＋ ⭐ **按音色不同的 ADSR** ✅） |
| ⭐ 5 | ⭐ **Test Mode 已实装** | ⭐ ⚠️ 本文"`M` 命令是空桩"**已作废** ✅（⭐ 串口 `M` 循环 **4/8/16/32** ✅ · ⭐ 判据 `sim\test_mode_fft.ps1` ✅） |
| ⭐ 6 | 🔴 **`SEL_DRUM` 默认 = 1（鼓机）**（⭐ **2026-09-30 深夜用户裁定改的**） | ⭐ **默认 bitstream = 鼓机** ✅（⚠️ 那份里**节拍器不响** —— 源 B 二选一 ✅）<br>⚠️ **但源 B 上电【静音】**（运行时 `met_on_r` 复位 = 0）⇒ ⭐ **要发串口 `'B'` 才响** ✅<br>📌 旧口径"默认 = 0（节拍器）/ 要听鼓机必须另编" 🔴 **已作废** ✅ |
| ⭐ 7 | ⭐ **looper 回放带【录制时的音色】** | ⭐ 录进去什么音色，⭐ 回放就是什么 ✅（⭐ 录制中途换音色也各自保留 ✅） |
| ⭐ 8 | ⭐ **鼓机第 4 件乐器 = 嗵鼓** | ⭐ ⛔ **不是拍手** ✅ —— ⭐ 4 类 = ⭐ **大鼓 · 小鼓 · 嗵鼓 · 镲** ✅ |
| ⭐ 9 | ⚠️ **已知未修（⭐ 先别当故障）** | ⭐ **快按/重按的起音不稳**（⭐ `K-169` 已改挂事件边沿，⭐ **待上板验** ✅）· ⭐ **力度缺陷**（⭐ 两侧都没修好，⭐ 暂保留 ✅）· ⭐ **回放力度/尾音**（⭐ A2 已做，⭐ 待上板验 ✅） |
| ⭐ 10 | 🔴 **烧录前必查时序** | ⭐ 最近一版 PnR **时序不达标**（⭐ Fmax 43.66 MHz / 1702 setup 违例 ⚠️）⇒ ⭐ **正在修** ✅ ⇒ ⭐ **烧之前先确认那份 `.fs` 的 `timing.txt` 是 0 setup / 0 hold** ✅ |

> 📌 ⭐ 串口命令的**完整现行表**：⭐ `T S X P V M N R L C I` ＋ ⭐ **`B`（节拍器）** ＋ ⭐ **`D`（鼓机节奏型）** ✅
> ⚠️ 波特率仍是 **500000**（⭐ 8N1 ✅）；⭐ 发**单个 ASCII 字符** ✅

---

## 一、⭐ 出发前（⭐ 电脑前，~15 分钟）

| ✅ | 事项 | ⭐ 判据 / 命令 |
|---|---|---|
| ☐ | ⭐ **确认 `.fs` 是最新的** | ⭐ `impl/pnr/Gowin2026.fs` 时间戳应是 **2026-09-29 03:45** 左右 · ⭐ 大小 ≈ **18.4 MB**<br>⚠️ 若不对 ⇒ ⭐ 重跑 `powershell -NoProfile -ExecutionPolicy Bypass -File sim\gowin_build.ps1`（⭐ ~10 分钟） |
| ☐ | ⭐ 确认 **0 setup / 0 hold** | ⭐ 脚本尾部打 `OK PnR report is fresh` ✅ |
| ☐ | ⚠️ **确认器件型号（⛔ 别看 `pn=` 属性！）** | ⭐ 判据 = **PnR 报告里实际用的料号**：`Select-String -Path impl\pnr\Gowin2026.rpt.txt -Pattern 'Part Number'` ⇒ ⭐ **必须是 `GW5AT-LV60PG484AC1/I0`**<br>⚠️ `Gowin2026.gprj` 的 `pn=` 属性**⛔ 不决定器件** —— ⭐ 它一直写着 `AC1/I0`，而实际构建**一直是 `AC2/I1`** ⚠️（⭐ 见 `K-170`）<br>⭐ IDE 里选 **`Package = PBG484A`** · **`Device Version = B`** |
| ☐ | ⭐ 装 **`pyserial`** | ⭐ `python -m pip install pyserial`（⭐ `probe_q.py` 要用） |
| ☐ | ⭐ 串口助手设 **500000** | ⚠️ **⛔ 不是 1000000**（⭐ 见铁律 1） |
| ☐ | ⭐ 准备**万用表** ＋ **杜邦线/排线** ＋ **USB-C 线** | ⚠️ 没表就别上电 |
| ☐ | ⭐ 打印/打开本手册 | — |

---

## 二、⭐ 烧录（⭐ ~5 分钟）

### ⭐ 一句话：**一根 USB-C 插 Console 的 `/USB_JTAG/` 口就行**（⭐ 板载 BL616 当 JTAG 桥，⛔ 不用外部调试器）

```powershell
cd C:\Users\hokuu\Desktop\FPGA\FPGA2026

& "C:\Gowin\Gowin_V1.9.12.03_x64\Programmer\bin\programmer_cli.exe" `
  --device GW5AT-60B `
  --fsFile "C:\Users\hokuu\Desktop\FPGA\FPGA2026\impl\pnr\Gowin2026.fs" `
  --operation_index 1 `
  --cable "USB Debugger A"
```

| ⚠️ 注意 | ⭐ 说明 |
|---|---|
| ⭐ **`--operation_index 1`** | ⭐ = **烧写**（⭐ `0` 只读 ID，⚠️ **看着成功但没烧**） |
| ⭐ **`.fs` 是 SRAM 配置** | 🔴 **断电就丢** ⇒ ⭐ **先烧，再听** |
| ⭐ 也可以用 **Gowin Programmer 图形界面** | ⭐ 打开 `.fs` ⇒ 勾 **Program/Configure** ⇒ Run ✅ |

### ✅ 预期现象

| ⭐ 观察点 | ⭐ 预期 |
|---|---|
| Programmer 日志 | ⭐ `... Success` · **0 error** |
| ⭐ **心跳灯 `V13`** | ⭐⭐ **绿灯闪，约 1 Hz** —— ⭐ **这是唯一的"活体见证"** ✅ |
| ⚠️ 若心跳**不闪** | 🔴 **停下** —— ⭐ 说明时钟/配置有问题，⛔ 别继续 |

### 🔴 烧录失败排查

| ⭐ 症状 | ⚠️ 最可能 | ⭐ 怎么办 |
|---|---|---|
| 扫不到器件 | ⭐ 线插错口 / 没插稳 | ⭐ 换 USB-C 口 · ⭐ 换线 |
| 扫到但烧失败 | 🔴 **器件型号不匹配** | ⭐ 确认 `AC1/I0` ＋ IDE 里 `PBG484A` + `Version B` |
| 完全没反应 | 🔴 没供电 | ⭐ 先量 3V3/5V |

### 🔴 ⛔ 绝对不要碰的引脚：**JTAG 四根**

```
⭐ TMS=T13 · TDO=U13 · TCK=V12 · TDI=R13（⭐ 全在 BANK12）
⇒ ⛔ 不要接任何外设、⛔ 不要分配成 IO
```

---

## 三、⭐ 接线（⭐ ~15 分钟）

### 3.1 ⭐⭐ 左手板 `SPI_n` 座 → Console **`J9`**（⭐ **核心接线**）

| ⭐ 左手板信号 | ⭐ `J9` 针 | ⭐ 信号名 | ⭐ ball |
|---|---|---|---|
| **`MCP_CLK`** | **`N1`** | `spi_sclk` | `E14` |
| **`MOSI`** | **`N2`** | `spi_mosi` | `E13` |
| **`MISO`** | ⭐ **`N3`** | `spi_miso[0]` | `C15` |
| **`CS`** | ⭐ **`N4`** | `spi_cs_n[0]` | `C14` |
| **`+5V`** | **`N11`** | ⭐ 给左手板供电 | — |
| **`GND`** | **`N12`** | ⭐ 共地 | — |

⇒ ⭐ **信号线 = 4 根** ＋ ⭐ **地线多接几根**（⭐ 左手板 2/4/6/8 都是 GND）✅
⚠️ `N5`~`N10`、`N13`~`N16`（片 1~5）**今天留空**，🔴 **但排线别剪断** ✅

### 3.2 ⭐ 左手板电源座（⭐ 4 个）

| ⭐ 座 | ⭐ 针序 |
|---|---|
| **`模拟电源n`** | `.1 .3` = **`5V_A`** · `.2 .4` = **`AGND`** |
| **`数字电源n`** | `.1 .3` = **`5V`** · `.2 .4` = **`GND`** |

✅ **插反不会短路**（⭐ 都是 VCC/GND 交错）✅

### 3.3 ⭐ 外置 I2S DAC（⭐ 接贝斯音箱 —— ⛔ 别接板载 `J5`）

> 🔴 **`J5` 是已放大的 BTL 输出 ⇒ 直连有源音箱会烧**（⭐ BTL 任一端不能接地）✅

| ⭐ 模块丝印 | ⭐ 接到 | ⚠️ |
|---|---|---|
| `VIN` | **5V** | 🔴 **不是 3.3V** |
| `GND` | GND | ⭐ 共地 |
| `LCK` | **`E22`** | ⚠️ **三根挨着，逐根对** |
| `DIN` | **`D22`** | ⚠️ 同上 |
| `BCK` | **`F20`** | ⚠️ 同上 |
| `SCK` | **GND** | 🔴 **必须接地**（⭐ 内部 PLL 要求） |
| `XSMT` | **3V3** | 🔴 **低 = 软静音** |
| `FMT` | **3V3** | ⭐ = 左对齐 |
| `FLT` / `DEMP` | GND | ⭐ 本次可试 `FLT`→3V3 |

```
⚠️ 丝印陷阱（⭐ 上次三根全错）：
   🔴 模块丝印只标 6 个脚，⭐ 而排针 JP1 实际有 11 个
      （11/10 VCC · 9 GND · 8 FLT · 7 DEMP · 6 SCK · 5 BCK · 4 DIN · 3 LRCK · 2 FMT · 1 XSMT）
   ⇒ ⭐ **务必先确认 1 脚位置（方形焊盘）**，⭐ 按丝印名逐根接 ✅
```

### 🔴🔴 一个【别乱改】的地方：两路 I2S 的参数**故意不同**

| ⭐ 那一路 | ⭐ 器件 | ⭐ `JUSTIFY` | ⭐ **`MSB_DELAY`** | ⭐ 依据 |
|---|---|---|---|---|
| ⭐ **板载** | `MAX98357A` | `0` | ⭐ **`1`**（标准 I2S） | ✅ 已验证 |
| ⭐ **外置** | `PCM5102A` | `0` | ⭐ **`0`**（左对齐） | ⭐ **2026-09-26 上板实测**：`FORMAT_SEL=1`（MSB 无延后）**出声**，`=0`（标准 I2S）**没声** |

```
🔴 **⛔ 别把外置那路改成 MSB_DELAY=1** —— ⚠️ 旧文档（`bringup/15-…`）
   说"若 DIN 差 1 位就把 0 改成 1"，⭐ **那条建议已过时**（⭐ 实测外置要 0）✅
📌 术语陷阱：⭐ `i2s_tx` 里的 `JUSTIFY=0` 指的是 **"Philips 标准 I2S"**，
   ⚠️ ⛔ **不是**字面意义的"左对齐" ⇒ ⭐ 真要左对齐 = `JUSTIFY=0` + `MSB_DELAY=0` ✅
```

### ⭐ 频率口径（⭐ 两路一样）

| ⭐ 信号 | ⭐ 频率 | ⭐ 依据 |
|---|---|---|
| `BCK` | ⭐ **3.125 MHz** | ⭐ `BCLK_DIV = 16`（⭐ 50 MHz ÷ 16） |
| `WS` / `LRCK` | ⭐ **48.828 kHz** | ⭐ `SLOT_BITS = 32` × 2 声道 ⇒ 3.125 MHz ÷ 64 |

### 3.4 🔴 串口（⭐ **2026-09-30 深夜更正**：必须**外接 USB-TTL**，⛔ 走不了板载 USB-C）

> 🔴🔴 **本节原文（"一根 USB-C 线即可 / ⛔ 不用买 USB-TTL"）【已作废】** ——
> ⭐ **用户 2026-09-30 上板亲验**：⭐ **板载 USB-C 的串口走不通** ⇒ ⭐ **必须走 `J9` 排针**。
> 📌 与 `constr/top.cst:331-357` 的实测记录一致：
>    · 🔴 板载 `BL616` 跑 **`TangCore` 固件** ⇒ 它的 UART 是**私有协议（2 Mbps）**
>      ⇒ **⛔ 不透传我们的 `T`/`S`/`X`**（⭐ 实测：发任何字节都被"**回显**"）
>    · 🔴 而 `V14`/`U15` **只在 `J2` 板对板连接器上**（0.4 mm 间距）⇒ 🔴 **物理上插不了线**

```
⭐ USB-TTL 的 TX   →  J9 的 N26   （ D14 = uart_rx ）
⭐ USB-TTL 的 RX   →  J9 的 N25   （ D15 = uart_tx ）
⭐ USB-TTL 的 GND  →  J9 的 GND
⇒ ⭐ 500000 baud · 8N1 · ⛔ 无流控        （⭐ J9 = 2.54 mm 排针，杜邦线可插）
```

⭐ **驱动工具**：`python tools\board_probe.py <COM口> --send ...`（⭐ 带时间戳）
📌 **详见** ⭐ `bringup/18-上板验证卡-功能修复-20260930深夜.md` §1.1

### ✅ 接线完成后的预期（⭐ 万用表蜂鸣档）

```
⭐ SPI 座.1(CS)   ↔ J9.N4  ⇒ 【通】
⭐ SPI 座.3(CLK)  ↔ J9.N1  ⇒ 【通】
⭐ SPI 座.5(MOSI) ↔ J9.N2  ⇒ 【通】
⭐ SPI 座.7(MISO) ↔ J9.N3  ⇒ 【通】
⭐ SPI 座.2/4/6/8(GND) ↔ J9.N12 ⇒ 【通】
⚠️ 相邻信号之间（如 N1↔N2）⇒ 🔴 **必须【不通】**
```

---

## 四、⭐ 不上电检查（⭐ ~10 分钟，别跳）

| ✅ | 检查项 | ⭐ 判据 |
|---|---|---|
| ☐ | **3V3 对 GND 电阻** | ⚠️ **不能是 0** ⇒ ⭐ 应 **> 100 Ω** |
| ☐ | **5V 对 GND** | ⭐ 同上 |
| ☐ | ⭐ 逐根核对 **4 根信号线** | ⭐ **逐根确认**，⛔ 别凭印象 |
| ☐ | 确认左手板**没和 `SDRAM` 冲突** | ⚠️ `PMOD`/`SDRAM` 是 **0Ω 二选一** |
| ☐ | 确认 **`PA_EN_n`（`Y14`）悬空** | ⚠️ 由 FPGA 驱动，⛔ 别外接下拉 |

### ⭐ 三条铁律（⛔ 违反会白忙）

| # | ⭐ 铁律 | ⭐ 为什么 |
|---|---|---|
| **1** | ⭐ **每次上电前先量 3V3 和 5V** | 🔴 接错电源会**烧板子**（不可逆） |
| **2** | ⭐⭐ **`PA_EN_n`（`Y14`）对 Console 必须【高】** | 🔴 它接 `MAX98357A` 的 `SD_MODE`，⚠️ **低 = Shutdown = 无声**（⭐ 而波形全对！）<br>⭐ `top.v` 默认 `PA_ON_AFTER_RESET=1` ⇒ ✅ **默认就是对的** |
| **3** | ⭐ **一次只改一个变量** | 🔴 同时改接线＋参数 ⇒ 出问题不知道是谁的 |

---

## 五、⭐ 阶梯验证（⭐ 逐级过，⛔ 别跳级）

> ⭐ **原则**：⭐ 每级都有"预期现象" —— ⚠️ **现象不符就停下**。

### 阶梯 1 · 板子活着

| ⭐ 步 | ⭐ 操作 | ⭐ **预期** |
|---|---|---|
| 1 | 上电 | ⭐ 板上电源灯亮 |
| 2 | 看 **`CFG_LED`（`V13`）** | ⭐⭐ **绿灯闪 ~1 Hz** |
| 3 | ⚠️ 若不闪 | 🔴 **停下** —— ⭐ 时钟/配置有问题 |

### 阶梯 2 · I2S 三线（⚠️ 没示波器可跳过）

| ⭐ 测点 | ⭐ **预期**（⭐ 实测值） |
|---|---|
| `HP_BCK`（`Y17`） | ⭐ **3.125 MHz** 方波 |
| `HP_WS`（`AB17`） | ⭐ **48.828 kHz** 方波（⭐ 占空比 50%） |
| `HP_DIN`（`AA16`） | ⭐ **有数据在动**（⛔ 不是恒定电平） |

### 阶梯 3 · ⭐ 听到自检和弦

| ⭐ 步 | ⭐ 操作 | ⭐ **预期** |
|---|---|---|
| 1 | ⭐ 上电后**别按键**，安静听 | ⭐⭐ 约 **200 ms** 后听到一个和弦 |
| 2 | 听音高 | ⭐ **A4(440) + C#5(554) + E5(659)**（⭐ A 大三和弦） |
| 3 | 听时长 | ⭐ **约 1 秒后自己停** |
| 4 | 之后 | ⭐ **安静**（⛔ 不是一直响） |

```
⭐⭐ 这一级说明：⭐ 合成链（DDS + 波表 + ADSR + 混音 + I2S + DAC）【全通】✅
```

### 阶梯 4 · ⭐⭐ 按琴键出声（⭐ **本周硬指标**）

| ⭐ 步 | ⭐ 操作 | ⭐ **预期** |
|---|---|---|
| 1 | 上电后**什么都不按**，等 ~2 秒 | ⭐ `autotare` 跑完（⭐ 16 轴记零点） |
| 2 | **轻按**轴 0（~30%） | ⭐ **听到声音**（⭐ 较小） |
| 3 | **用力按**轴 0（按到底） | ⭐ **声音更大** |
| 4 | **松开** | ⭐ **声音衰减**（⭐ 约 0.45 秒后静音） |
| 5 | 换轴 1、2、3… 逐个试 | ⭐ 每轴都能出声 |

### 阶梯 5 · ⭐ 节拍器（⭐ 按 `AB13` 那个键）

| ⭐ 步 | ⭐ 操作 | ⭐ **预期** |
|---|---|---|
| 1 | ⭐ 按一下 **`AB13`**（⭐ 节拍器开关，⭐ 复位后默认**关**） | ⭐ 开始打拍 |
| 2 | 听音高 | ⭐ **强拍 / 弱拍 两种音高**（⭐ 第一拍是强拍） |
| 3 | 再按一下 | ⭐ **停** |

⚠️ **⛔ 别按 `Y12`** —— ⭐ 那是 `Key_in[1]`（⭐ ESP32 线预留），⛔ **不是复位** ✅
⭐ **复位键 = `AA13`**（⭐ Console 板上那个复位按钮）✅

### 阶梯 6 · ⭐⭐ **Looper（⭐ 本轮新功能，首次上板）**

> ⚠️ **前提**：⭐ 串口连好（⭐ 见 §3.4），⭐ 波特率 **500000**。
> ⭐ **命令**：`R` = 录/停**切换** · `L` = 播放**切换** · `C` = 清空

| ⭐ 步 | ⭐ 操作 | ⭐ **预期** |
|---|---|---|
| 1 | ⭐ 发 **`R`** ⇒ ⭐ **弹几个音**（⭐ 会边弹边录）⇒ ⭐ 再发 **`R`** 停录 | ⭐ 停止后**安静** |
| 2 | ⭐ 发 **`L`** | ⭐⭐ **刚才弹的那段【循环播放】** ✅ |
| 3 | ⭐ 播放中**再弹琴** | ⭐⭐ **手弹和 loop【同时出声】**（⭐ 这就是"边 loop 边弹"）✅ |
| 4 | ⭐ 发 **`L`** 停播 | ⭐ 停 |
| 5 | ⭐ 发 **`C`** 清空 ⇒ ⭐ 再发 `L` | ⭐ **不出声**（⭐ 已清空）✅ |

```
⚠️ 两个已知限制（⭐ 不是故障）：
   ① ⭐ looper 与【曲谱灌入】共用同一个内部口 ⇒ ⭐ 本版 SCORE_UART_ENABLE=0
      ⇒ ⭐ **灌曲谱【不生效】**，⭐ 但 looper 可用 ✅
   ② ⭐ looper 的【可观测口还没接上板】⇒ ⭐ 录满 / 溢出【看不见】
      ⇒ ⚠️ 录太长（> 2048 条事件）会静默丢 ⇒ ⭐ **录短一点（几秒）** ✅
```

---

## 六、⭐⭐ 串口命令全表（⭐ 帧外才认，⭐ 一次一个字符）

| ⭐ 命令 | ⭐ 作用 | ⭐ **预期回包** |
|---|---|---|
| **`T`** | ⭐ 重新逐轴记零点（16 轴） | ⭐ 先 `t`，⭐ 1~2 秒后 `T`（⭐ 大写 = 完成） |
| **`S`** | ⭐ 启动 `span` 标定 | ⭐ `s`，⭐ 然后逐轴回包（⚠️ 见下） |
| **`X`** | ⭐ 取消当前标定 | ⭐ `x` |
| ⭐ **`P`** | ⭐ **诊断：回当前扫描通道的【原始码】** | ⭐ `P<ch><pos>`（⭐ 8 字节） |
| ⭐ **`N`** | ⭐ **诊断：回【标定后的 `pos`】**（⭐ 每次轮换一个轴） | ⭐ `N<ax><pos>` |
| ⭐ **`V`** | ⭐ 诊断：回 `span` 内部状态 | — |
| **`M`** | ⭐ Test Mode 下一档（4/8/16/32/关） | ⚠️ `test_mode` 仍是**空桩** ⇒ ⭐ **目前无实际效果** |
| ⭐ **`R`** | ⭐ **Looper：录/停切换** | — |
| ⭐ **`L`** | ⭐ **Looper：播放切换** | — |
| ⭐ **`C`** | ⭐ **Looper：清空** | — |
| ⭐⭐ **`I`** | ⭐⭐ **切音色**（⭐ 每按一次 `0→1→2→3→0` ✅） | ⭐ **听感直接变** ✅<br>⭐ `0`=**BASS 三角** · ⭐ `1`=**GUITAR 锯齿** · ⭐ `2`=**PIANO 25% 方波** · ⭐ `3`=**PAD**<br>⚠️ ⭐ **只对【新按下的音】生效** —— ⭐ 音色是**在起音那一刻锁存到每个 voice** 的（⭐ `note_manager.v:413` ✅）⇒ ⭐ **已经在响的音保持原音色** ✅（⭐ 这是对的 ✅，⭐ 但会让人疑惑 ✅）<br>📌 ⭐ **验证手法**：⭐ 发 `I` ⇒ ⭐ **松开再按**同一个键 ⇒ ⭐ 音色立刻变 ✅<br>📌 ⭐ **2026-09-29 新增** —— ⚠️ 以前音色**写死 0**、⭐ 换不了 ✅ |

### ⚠️ `span` 标定的已知坑（⭐ `K-126`，⭐ 未修）

```
🔴 实测：发 'S' 只回 's'（受理），🔴 **之后【没有】任何轴号提示**
   ⇒ ⭐ 根因：轴号提示只待 1 拍（20 ns），⭐ 而 uart_tx 正在发 's'（~20 µs）
      ⇒ 🔴 请求被丢，⛔ 不重发
⇒ ⭐⭐ **操作办法：⭐ 盲按** —— ⭐ 按 `cur_axis` 顺序 **0 → 1 → 2 …** 逐个按到底
   ① 发 'S' ⇒ 回 's'
   ② 按【轴 0】到底、⛔ 停住 1~2 秒 ⇒ ⭐ 成功回 '.'，失败回 '!'
   ③ 再按【轴 1】…… 直到回 'D'（⭐ 16 轴全部完成）
   ⚠️ 最多每轴重试 8 次，⭐ 反复失败回 'E' ⇒ 重发 'S' 重来
```

> ⚠️ **2026-09-30 夜更正**：⭐ **`K-126` 已修**（⭐ `rtl/top.v:872` 的 `uart_tx_fifo` 就是它的修法；
> ⭐ 注释原文"单拍也可（当拍即入队）"）⇒ ⭐ **轴号提示不会丢** ⇒ ⛔ **"盲按"那条操作办法已过时** ✅
> ⭐ 当晚上板实测已看到 `s`＋轴号＋原因码（⭐ 见 `bringup/18-上板验证卡-功能修复-20260930深夜.md`）✅

⚠️ **发命令会让 `evt_uart_rx` 的错误计数涨** —— 🔴 **正常，⛔ 不是故障** ✅

---

## 七、⭐⭐ 本轮三个头号测量（⭐ 按优先级）

### 7.1 ⭐⭐ 测 A：**`raw` 到底跳不跳？**（⭐ 定"又响又尖"的根因）

> ⭐ **这是本次上板【唯一能定性】的测量** —— ⭐ 交接文档说根因"必须上板"✅

```cmd
cd /d C:\Users\hokuu\Desktop\FPGA\FPGA2026
python tools\probe_q.py COM32 60 0.3
```

⭐ **边跑边【用力敲打】几个键**（⭐ 越快越好），⭐ 然后看输出末尾的
**`RAW ADC CODE per channel`** 里的 **SPREAD** 列：

| ⭐ 该轴 `P` 的 **SPREAD** | ⇒ ⭐ 结论 |
|---|---|
| ⭐ **~500+** | ⭐ **原始读数真的在摆** ⇒ **霍尔 / 机械** ⇒ ⭐ 修法 = 中值滤波 / 变化率限幅 |
| ⭐ **~20** | ⭐ **原始读数干净** ⇒ 🔴 **跳变是下游造出来的** ⇒ ⭐ 查 `calib` 标定链 / ADC-SPI 读错 |

⚠️ **两个注意**：
1. ⭐ **波特率 500000**（⭐ `probe_q.py` 自己就是这个值）✅
2. ⚠️ **`Q` 包默认不回**（⭐ `DPOS_DIAG=0`）—— ⭐ **但"按通道 spread"用的是 `P` 包，⭐ 不需要它** ✅

### 7.2 ⭐⭐ 测 B：**"又响又尖"还在不在？**（⭐ 头号待办）

| ⭐ 步 | ⭐ 操作 | ⭐ **记录** |
|---|---|---|
| 1 | ⭐ **正常力度**弹一段 | ⭐ 干净吗？ |
| 2 | ⭐ **用力敲打**同一个键 | 🔴 **是否出现"又响又尖"**？ |
| 3 | ⭐ **按住不动** | ⭐ 有没有？（⭐ 用来分"稳态"还是"瞬态"） |
| 4 | ⭐ 同时按 3~4 个键 | ⭐ 是否破/糊？ |

⭐ **四问分诊表**（⭐ `K-152`，⭐ 决定查哪条链）：

| ⭐ 问 | ⭐ 答案 ⇒ 查哪里 |
|---|---|
| ⭐ **周期性 还是 瞬时？** | 周期 ⇒ 波形/振荡器/波表 · 瞬时 ⇒ 事件/包络/增益 |
| ⭐ **跟按键力度有关吗？** | 有关 ⇒ **输入链**（`pos`/ADC/力度）· 无关 ⇒ **音频链** |
| ⭐ **跟复音数有关吗？** | 有关 ⇒ 混音/归一化/限幅器 · 无关 ⇒ 单 voice 内部 |
| ⭐ **按住不动就有吗？** | 有 ⇒ 稳态路径 · 只在变化时 ⇒ 瞬态路径 |

> ⭐⭐ **当前状态（⭐ 诚实说明）**：⭐ **"又响又尖"的根因【仍未确认】** ——
> ⭐ **两条假设（削波 / 力度突变）都已被实测否定**（⭐ 见交接文档 §四）。
> ⇒ ⭐ **所以这次上板是"取数据"，⭐ ⛔ 不是"验证已知结论"** ✅

### 7.3 ⭐ 测 C：**Looper 首次上板**（⭐ 见 §五 阶梯 6）

⭐ **带回**：⭐ 录了多久 · ⭐ 循环对不对拍 · ⭐ "边 loop 边弹"有没有声 · ⭐ 有没有**长鸣**（⭐ 挂音）✅

---

## 八、🔴 出问题时的排查顺序

| ⭐ 症状 | ⭐ **最可能** | ⭐ 怎么查 |
|---|---|---|
| 🔴 **完全没声** | ⭐ `PA_EN_n` 低 / ADC 没读到 | ⭐ **先量 `Y14`**（⭐ 必须**高**） |
| 🔴 **一上电就恒响** | 🔴 所有轴被判"按下" | ⭐ `pos` 恒高 ⇒ ⚠️ `tare` 没做 / 极性反了 |
| ⚠️ **读数乱跳** | ⚠️ 排线干扰 / 霍尔本身 | ⭐ 跑 `probe_q.py` 看 spread（⭐ 见 §7.1） |
| ⚠️ **按轻按重一个样** | ⚠️ 力度阈值 | ⭐ 查 `.POS_FULL` 是否匹配实际行程 |
| 🔴 **心跳不闪** | 🔴 烧录失败 / 时钟没起 | ⭐ 重新烧 · ⭐ 示波器量 `V22`（50 MHz） |
| ⚠️ **串口没回话** | 🔴 **波特率错**（⭐ 应 **500000**）/ 线没插好 | ⭐ 确认 500000 ＋ ⭐ **发单个 ASCII 字符**（⛔ 不是字符串） |
| ⚠️ **`probe_q.py` 没有 `Q` 包** | ⭐ **正常**（`DPOS_DIAG=0`） | ⭐ 只看 `P`/`N` ✅ |

---

## 九、⛔ 今天【测不到】什么（⭐ 别以为是故障）

| # | ⭐ 项 | ⚠️ 为什么 |
|---|---|---|
| **1** | 🔴 **串口灌曲谱** | ⭐ `SCORE_UART_ENABLE = 0` ⇒ ⭐ **不生效**（⭐ 那个口现在归 looper） |
| **2** | 🔴 **鼓机** | ⭐ `SEL_DRUM = 0` ⇒ ⭐ 默认 bitstream 里**没有它**（⭐ 被综合器扫掉） |
| **3** | 🔴 **`Q<轴><dpos>` 诊断包** | ⭐ `DPOS_DIAG = 0` ⇒ ⭐ 要它就得改 1 重跑 PnR |
| **4** | ⚠️ **`raw` 中值滤波** | ⭐ `RAW_MEDIAN_EN = 0` ⇒ ⭐ **没开**（⭐ 这是要测的对象，⛔ 不是故障） |
| **5** | ⚠️ **`test_mode`（4/8/16/32 复音）** | 🔴 **它仍是空桩**（⭐ 队友的活）⇒ ⭐ `M` 命令**无实际效果** |
| **6** | ⚠️ **四音色** | ⭐ `wavetable_bank` 只有**单音色** ⇒ ⭐ 音色分不开 |
| **7** | ⚠️ **Looper 的"录满/溢出"可见性** | ⭐ 观测口**没接上板** ⇒ ⭐ 录太长会**静默丢** |

---

## 十、⭐ 记录表（⭐ 每测一项就填，⛔ 别凭记忆）

| ✅ | 项 | ⭐ 实测 |
|---|---|---|
| ☐ | `.fs` 时间戳 / 大小 | |
| ☐ | 烧录结果（Success / error 数） | |
| ☐ | 心跳闪不闪 | |
| ☐ | 自检和弦：听到没 / 时长 | |
| ☐ | 按琴键：哪些轴有声 / 有无力度差异 | |
| ☐ | 节拍器：强拍弱拍分不分得开 | |
| ☐ | ⭐ **`probe_q.py` 各轴 SPREAD**（⭐ 贴原始输出） | |
| ☐ | ⭐ **"又响又尖"**：正常 / 用力敲 / 按住 / 多键 | |
| ☐ | ⭐ **Looper**：录 / 循环 / 边 loop 边弹 / 有无长鸣 | |
| ☐ | 其它异常（⭐ 拍照/录屏） | |

---

## 十一、🔁 **复测清单（⭐ 2026-09-29 下午版 · 修完 3 个 bug 后重上板）**

> ⭐ **烧新 `.fs`**（⭐ 含 bug①②③ 的修复 ✅）⇒ ⭐ **按下面顺序测** ✅

| ⭐ 序 | ⭐ 测什么 | ⭐ 操作 | ⭐ **预期（⭐ 修复后）** | ⭐ 若不对 |
|---|---|---|---|---|
| **1** | ⭐⭐ **bug②：还有没有"电子音"** | ⭐ **按一个键到底**（⭐ 靠近底部） | ✅⭐ **音色不再变"电子"** —— ⭐ 全程都是**同一个音色**（⭐ 只是变响 ✅）<br>⚠️ ⭐ **力度→音量仍然有效**（⭐ 这是你要的 ✅） | 🔴 记下"哪个轴、按多深、什么音" |
| **2** | ⭐⭐ **bug①：`C` 清空还挂不挂音** | ⭐ 录一段 ⇒ `L` 播放 ⇒ ⭐ **播放中发 `C`** | ✅⭐ **声音立刻干净停掉**（⭐ 不再有长鸣 ✅） | 🔴 记下"挂的是哪个音、多久" |
| **3** | ⭐ **bug③：`Q` 包** | ⭐ `python tools\probe_q.py COM32 60 0.3` ⇒ ⭐ **边跑边用力敲键** | ✅⭐ **每行都有 `Q<轴><dpos>`** ⇒ ⭐ 看 `dpos` 有多大<br>⭐ **`dpos` ~ 几十** ⇒ 霍尔干净 · ⭐ **~ 700+** ⇒ 霍尔在跳 | 🔴 贴原始输出 |
| **4** | ⭐ **`P` 的按通道 spread** | ⭐ 同上（⭐ 看输出**末尾那张表** ✅） | ⭐ 每个通道一行 SPREAD | 🔴 贴原始输出 |
| **5** | ⚠️ **bug④：尖音** | ⭐ 用力敲打 | ⚠️ **已减轻、未完全解决**（⭐ 记录即可 ✅） | 🔴 记下频率/力度 |

### 🔴🔴 **示波器捕获：⛔ 千万别再用 5 ms 的窗口**

```
🔴 **实测教训（2026-09-29）**：⭐ 第一份 CSV 的窗口只有 **5 ms**
   ⇒ ⭐ 而 C3 的周期 = **7.6 ms** ⇒ 🔴 **连【一个】音频周期都装不下**
   ⇒ ⭐ FFT 完全无意义（⭐ 我算出的"谐波"其实是【主瓣泄漏】）✅
```

| ⭐ 设置 | ⭐ **必须** |
|---|---|
| ⭐ **时基** | ⭐ **10 ms/格 × 10 格 = 100 ms**（⭐ 至少 20 ms ✅） |
| ⭐ **采样率** | ⭐ 会自动降到 ~**100 kHz**（⭐ 130 Hz 仍有 **760 点/周期** ✅） |
| ⭐ **纵轴** | ⭐ 按被测节点选（⭐ 上次 2 mV/div ⇒ ⭐ **毫伏级节点** ⚠️） |
| ⭐ **触发** | ⭐ 同一次按键（⭐ 便于对照 ✅） |
| ⭐ **两组对照** | ⭐ ① **轻按**（⭐ 正常音）⭐ ② **按到底**（⭐ 异常音）⇒ ⭐ **频谱相减** ⇒ ⭐ **一眼看出差在哪** ✅ |

> 📌 ⭐ **判据**：⭐ **谱形** ⇒ ⭐ 奇次为主且 h3 ≈ −19 dB ⇒ **三角波** · ⭐ 全偶次/奇次密集 ⇒ **削顶** · ⭐ 宽带抬高 ⇒ **干扰** ✅

### ⭐ 顺便量一下（⭐ 高价值）

| ⭐ # | ⭐ 测什么 | ⭐ 为什么 |
|---|---|---|
| **1** | ⭐ **`raw` 中值滤波**要不要开（⭐ 现在 `RAW_MEDIAN_EN = 0`） | ⭐ 看 §七 测 A 的 spread 再定 ✅ |
| **2** | ⭐ **`DPOS_DIAG` 的 `Q` 峰值** | ⭐ 直接回答"霍尔跳不跳" ✅ |
| **3** | ⭐ **looper 录长一点**（⭐ > 2048 条事件） | ⚠️ 观测口**没接上板** ⇒ ⭐ 会**静默丢** ⇒ ⭐ 先别录太长 ✅ |

---

## 附 · 关联文档

| ⭐ 想看什么 | ⭐ 去哪 |
|---|---|
| ⭐⭐ **接手必读（本轮全过程 + 8 个坑）** | `files/00-总览/交接文档-20260929.md` |
| ⭐ 深挖版上机指南 | `bringup/07-Console上机指南-20260924.md` |
| ⭐ 接线速查卡 | `files/10-硬件/接线速查卡-20260926.md` |
| ⭐ 外置 DAC 全量接线表 | `files/10-硬件/外置DAC模块接线表-20260926.md` |
| ⭐ 引脚真值（⭐ 权威） | `constr/top.cst` |
| ⭐ Console 引脚查证 | `files/10-硬件/板卡替换评估/Console引脚查证-20260922.md` |
| ⭐ `raw` 跳变 / `pos` 越界分析 | `files/20-代码/已知问题与风险清单.md` 的 `K-153` |
| ⭐ "又响又尖"分诊表 | 同上 `K-152` |
