hokuu1102/Gowin2026-PolySynth/bringup/10-上板操作卡-20260924.md

# 🖨️ Console 60K 上板操作卡（2026-09-24 下午 · **唯一照做版**）

> 🔴 **2026-09-29 更新：⭐ 本卡已被 `bringup/16-上板操作手册-20260929.md` 取代**
> ⇒ ⭐ **那份才是当前唯一照做版** ✅
> ⚠️ **本卡【两处口径已过时】**：
> ① 🔴 **串口波特率是 `500000`**（⭐ 本卡写的 **`1000000` 是错的** ⇒ ⚠️ 照它做会收到**乱码**）✅
> ② ⭐ 本轮新增了 **`P` / `N` / `V` / `R` / `L` / `C`** 命令（⭐ 含 **looper**）⇒ ⭐ **命令全表见新手册 §六** ✅
> 📌 本卡仍可作**深挖**用（⭐ 烧录 / 接线的**图文最全**）✅

> **用途**：⭐ **打印出来、照着打勾** —— ⚠️ **不用再翻长文档**。
> **流程总览**：⭐ **出发前 → 烧录 → 接线 → 上电检查 → 阶梯 1~4 → 串口标定**（⭐ 每步都有**预期现象**）
> **深挖版**（⭐ 出问题查这个）：`bringup/07-Console上机指南-20260924.md`
> **本轮新接通的功能**：⭐⭐ **串口标定（`T`/`S`/`X`）** —— ⭐ 见 §五
>
> ⚠️ **⚠️ 引脚已核对**（⭐ 权威：`constr/top.cst`）——
> 🔴 **如果你手上有 9/23 或更早打印的接线表 ⇒ 作废**。

---

## 📋 流程总览（⭐ 一张图看懂）

```
① 出发前（电脑前，~20 分钟）
     重建 bitstream · 装串口助手 · 打印本卡
        ↓
② 烧录（~5 分钟）           ⭐ 预期：CFG_LED 闪
     一根 USB-C → /USB_JTAG/ · Programmer 烧 .fs
        ↓
③ 接线（~15 分钟）           ⭐ 预期：万用表量通断
     左手板 SPI 座 → J9（4 根信号 + 地）· 电源座（4 个）
        ↓
④ 上电前检查（~15 分钟）     ⭐ 预期：3V3/5V 对地 > 100 Ω
        ↓
⑤ 上电 → 阶梯 1~4            ⭐ 每级都有预期现象
     心跳 → I2S → 自检和弦 → 按琴键出声
        ↓
⑥ 串口标定（T/S/X）          ⭐ 预期：打字就回字符
```

---

## 〇、⭐ 出发前（在电脑前做完）

| ✅ | 事项 | 判据/命令 |
|---|---|---|
| ☐ | ⭐ **重新构建**（⭐ 引脚/代码都变过） | `powershell -NoProfile -ExecutionPolicy Bypass -File sim\gowin_build.ps1`<br>⇒ ⭐ **exit 0** + 产出 `impl/pnr/Gowin2026.fs` |
| ☐ | ⭐ 确认 `0 setup / 0 hold` | ⭐ 脚本尾部会打 `OK PnR report is fresh` |
| ☐ | ⚠️ **确认器件型号对** | ⭐ 判据 = **PnR 报告实际用的料号**：`Select-String -Path impl\pnr\Gowin2026.rpt.txt -Pattern 'Part Number'` ⇒ ⭐ 必须是 `GW5AT-LV60PG484AC1/I0`<br>⚠️ ⛔ **别看 `.gprj` 的 `pn=` 属性** —— ⭐ 它**不决定器件**（⭐ 见 `K-170`）<br>⭐ IDE 里选 **`Package = PBG484A`** · **`Device Version = B`** |
| ☐ | ⚠️ **别用旧 `.fs`** | ⭐ 看时间戳（⭐ 应是你刚构建出来的时间） |
| ☐ | ⭐ 装好**串口助手** | ⭐ 波特率 **1000000**、8N1、⛔ 无流控<br>（⚠️ 选错会收到**乱码**、⛔ 不报错） |
| ☐ | ⭐ 打印/打开本卡 | — |
| ☐ | ⭐ 准备**万用表** + **杜邦线/排线** | ⚠️ 没表就别上电（⭐ 见 §三） |

### ✅ 预期现象（⭐ 构建成功后）

```
⭐ 命令尾部：=== Gowin build finished, exit code 0 ===
⭐ 命令尾部：bitstream: impl/pnr/Gowin2026.fs
⭐ 文件大小 ≈ 17 MB
```

---

## 〇之二、⭐⭐⭐ **怎么烧录**（⭐ 2026-09-24 核实）

### ⭐ 一句话：**插 USB-C 就行，⛔ 不用买外部调试器**

```
⭐ 原理图原文：⭐ 那个 USB-C 口的网络名就是 **`USB-JTAG(BL616)`**
⇒ ⭐⭐ **同一个口，两种功能**：
     PC ──USB-C──> BL616（USB-JTAG 桥）──┬─ **JTAG** ──> FPGA 配置口（⭐ **烧录用**）
                                        └─ **UART** ──> FPGA `V14`/`U15`（⭐ **串口用**）
```

### ⭐ 要烧的文件（⭐ 就这一个）

```
⭐ C:\Users\hokuu\Desktop\FPGA\FPGA2026\impl\pnr\Gowin2026.fs
```

### ⭐ 两种烧录工具（⭐ 二选一）

| # | ⭐ 工具 | ⚠️ 说明 |
|---|---|---|
| **①** | ⭐ **Gowin Programmer**（⭐ 官方 IDE 自带） | ⭐ 打开 `.fs` ⇒ **Program/Configure** |
| **②** | ⭐ **`openFPGALoader`**（⭐ 开源） | ⭐ `openFPGALoader -b tangmega60k <file>.fs`<br>⚠️ 板卡名要核实 |

### ⭐⭐ 烧录步骤（⭐ 逐屏）

```
① ⭐ 用一根 USB-C 线，插 Console 的 **`/USB_JTAG/`** 口
      ⚠️ Console 上【不止一个 USB 口】⇒ ⭐ 认准 `/USB_JTAG/` 那个
② ⭐ 看设备管理器：⭐ 应出现【一个串口（COMx）】
      ⚠️ 没出现 ⇒ ⭐ 换另一个 USB-C 口试试（⭐ 但别拔 12V）
③ ⭐ 打开 Gowin Programmer
④ ⭐ 点 "Scan Device"（或让它自动扫）
      ⇒ ⭐ **预期：扫到 `GW5AT-60B`**（⭐ 没扫到 ⇒ ⭐ 见下方"失败排查"）
⑤ ⭐ 添加文件：`impl/pnr/Gowin2026.fs`
⑥ ⭐ 勾选 **Program/Configure** ⇒ 点 **Run**
      ⇒ ⭐ **预期：进度条走完，最后报 `Success`（0 error）**
```

### ✅ 预期现象（⭐ 烧录成功）

| ⭐ 观察点 | ⭐ 预期 |
|---|---|
| **Programmer 日志** | ⭐ `... Success` · **0 error** |
| ⭐ **`CFG_LED`（`V13`）** | ⭐ **绿灯在闪，约 1 Hz**（⭐ 这是"活体见证"） |
| ⚠️ **若心跳不闪** | 🔴 **先停下** —— ⚠️ 说明时钟或配置有问题，⛔ **别继续** |

### 🔴 烧录失败排查（⭐ 3 条）

| ⭐ 症状 | ⚠️ 最可能的原因 | ⭐ 怎么办 |
|---|---|---|
| **扫不到器件** | ⭐ 线插错口 / 没插稳 | ⭐ 换 USB-C 口 · ⭐ 换线 |
| **扫到但烧失败** | 🔴 **器件型号不匹配** | ⭐ 确认 `.gprj` 是 `AC1/I0` · ⭐ IDE 里 `PBG484A` + `Version B` |
| **完全没有反应** | 🔴 **没供电** | ⭐ 见 §三（⭐ 先量 3V3/5V） |

### 🔴 **⛔ 绝对不要碰的引脚：JTAG 四根**

```
⭐⭐ 实测（原理图逐列对齐）：
   JTAG.TMS = T13   JTAG.TDO = U13   JTAG.TCK = V12   JTAG.TDI = R13
   └─ 全在 **`BANK12`** ─┘
⇒ 🔴 **这四根是烧录通道** ⇒ ⛔ **不要接任何外设、⛔ 不要分配成 IO**
```

### 🔴 **外部调试器能不能用？**（⭐ 已查原理图）

```
⭐ FPGA 的 JTAG 四根只连到两个地方：
   ① J0（`DF40HC(3.0)-80DS-0.4V`）—— 🔴 **板对板连接器，0.4 mm 间距**
      ⇒ ⚠️ **不是 2.54 mm 排针** ⇒ 🔴 **外部调试器插不进去**（⭐ 除非飞线）
   ② BL616 ⇒ ⭐ 就是"USB-C 当 JTAG 桥"
⇒ ⭐⭐ **结论：板载【没有】可插的 JTAG 排针。**
```
📌 **所以先用板载 USB-JTAG** —— ⚠️ "听说板载烧录垃圾" ⛔ **不等于"这台不行"**，
⭐ **判据就是：能烧进去 + `CFG_LED` 闪**。

---

## 一、⭐⭐ 三条铁律（⛔ 违反会白忙一夜）

| # | 铁律 | 为什么 |
|---|---|---|
| **1** | ⭐ **每次上电前先量 3V3 和 5V** | 🔴 接错电源会**烧板子**（不可逆） |
| **2** | ⭐⭐ **`PA_EN_n`（`Y14`）对 Console 必须【高】** | 🔴 它接 `MAX98357A` 的 `SD_MODE`<br>⚠️ **低 = Shutdown = 无声**（⭐ 而波形全对！）<br>⭐ `top.v` 默认 `PA_ON_AFTER_RESET=1` ⇒ ✅ **默认就是对的** |
| **3** | ⭐ **一次只改一个变量** | 🔴 同时改接线 + 参数 ⇒ 出问题不知道是谁的 |

---

## 二、⭐ 接线（⭐ 今天只接这些）

### 2.1 ⭐⭐ 左手板 `SPI_n` 座 → Console `J9`（⭐ **核心接线**）

#### ⭐ 左手板那一边（⭐ `SPI_n` 信号座，2.5 mm XH，8 针单排）

| ⭐ 针 | 1 | 2 | 3 | 4 | 5 | 6 | 7 | 8 |
|---|---|---|---|---|---|---|---|---|
| ⭐ 信号 | **`CS`** | `GND` | **`MCP_CLK`** | `GND` | **`MOSI`** | `GND` | **`MISO`** | `GND` |

#### ⭐ Console `J9` 这一边（⭐ 权威：`constr/top.cst`）

| ⭐ 左手板 | ⭐ `J9` 针 | ⭐ 信号 | ⭐ ball | ⭐ 方向 |
|---|---|---|---|---|
| **`MCP_CLK`** | **`N1`** | `spi_sclk` | `E14` | 出 |
| **`MOSI`** | **`N2`** | `spi_mosi` | `E13` | 出 |
| **`MISO`** | ⭐ **`N3`** | `spi_miso[0]`（⭐ 片 0） | `C15` | 入 |
| **`CS`** | ⭐ **`N4`** | `spi_cs_n[0]`（⭐ 片 0） | `C14` | 出 |

⇒ ⭐⭐ **要接的信号线 = 4 根**（`MCP_CLK` / `MOSI` / `MISO` / `CS`）
➕ ⭐ **地线**（⭐ 左手板 2/4/6/8 都是 `GND`）⇒ ⭐ **多接几根到 `J9` 的地**

| ⭐ 电源 | ⭐ `J9` 针 | ⭐ 说明 |
|---|---|---|
| **`+5V`** | **`N11`** | ⚠️ 给左手板供电 |
| **`GND`** | **`N12`** | ⭐ 共地 |

⚠️ `N5`~`N10`、`N13`~`N16`（片 1~片 5）**今天留空** —— 🔴 **但排线别剪断**。

⚠️ **`MISO` 必须每片独立**（`K-06`：`adc_farm` 是锁步并行，共享会**推挽对打**）。

### 2.2 ⭐ 左手板电源座（⭐ 4 个）

| ⭐ 座 | ⭐ 针序 | ⭐ 说明 |
|---|---|---|
| **`模拟电源n`** | `.1 .3` = **`5V_A`** · `.2 .4` = **`AGND`** | ⭐ 模拟域 |
| **`数字电源n`** | `.1 .3` = **`5V`** · `.2 .4` = **`GND`** | ⭐ 数字域 |

✅ **两个座插反【不会短路】** —— ⭐ 都是 `VCC/GND/VCC/GND` 交错排列。

### 2.3 🔴 串口（⭐ **2026-09-30 深夜更正**：必须**外接 USB-TTL**，⛔ 走不了板载 USB-C）

> 🔴 **原文（"一根 USB-C 线 / ⛔ 不用买 USB-TTL"）【已作废】** ——
> ⭐ 用户 2026-09-30 上板亲验：⭐ **板载 USB-C 的串口走不通** ⇒ ⭐ **必须走 `J9` 排针**。
> 📌 与 `constr/top.cst:331-357` 一致：板载 `BL616` 跑 `TangCore` 固件 ⇒ 其 UART 是**私有协议**
> ⇒ **⛔ 不透传 `T`/`S`/`X`**；而 `V14`/`U15` **只在 `J2`（0.4 mm）上** ⇒ 🔴 **插不了线**。

| 项 | ⭐ 做法 |
|---|---|
| **PC 连板子** | ⭐⭐ **外接 USB-TTL**：`TX→J9·N26`（`D14`=`uart_rx`）· `RX→J9·N25`（`D15`=`uart_tx`）· `GND→GND` |

```
⭐ 链路：⭐ PC ──USB-TTL──> J9（N25/N26 · 2.54 mm 排针）──> FPGA uart_rx / uart_tx
⇒ ⭐ 波特率 500000 · 8N1        （⚠️ ⛔ 不是 1000000）
```

### 2.4 ⭐ 板载固定（⛔ 不用接，⭐ 核对即可）

| ⭐ 信号 | ⭐ ball | ⭐ 说明 |
|---|---|---|
| **I2S** `HP_BCK`/`HP_WS`/`HP_DIN` | `Y17`/`AB17`/`AA16` | ⭐ 板载 DAC |
| **`PA_EN_n`** | `Y14` | ⭐ 功放使能（⭐ 铁律 2） |
| ⭐ **心跳** `led_heartbeat` | `V13` | ⭐ 唯一"活体见证" |
| **`rst_n`** | `AA13` | ⭐ 复位 |

### ✅ 接线完成后的预期（⭐ 万用表蜂鸣档）

```
⭐ 量 左手板 SPI 座.1(CS)   ↔ J9.N4   ⇒ ⭐ 【通】
⭐ 量 左手板 SPI 座.3(CLK)  ↔ J9.N1   ⇒ ⭐ 【通】
⭐ 量 左手板 SPI 座.5(MOSI) ↔ J9.N2   ⇒ ⭐ 【通】
⭐ 量 左手板 SPI 座.7(MISO) ↔ J9.N3   ⇒ ⭐ 【通】
⭐ 量 左手板 SPI 座.2/4/6/8(GND) ↔ J9.N12 ⇒ ⭐ 【通】
⚠️ 量 相邻信号之间（如 N1↔N2）⇒ 🔴 **必须【不通】**（⭐ 通了就是短路/接错）
```

---

## 三、⭐ 不上电检查（⭐ 15 分钟，别跳）

| ✅ | 检查项 | ⭐ 判据 |
|---|---|---|
| ☐ | 万用表量 **3V3 对 GND 电阻** | ⚠️ **不能是 0** ⇒ ⭐ 应 **> 100 Ω** |
| ☐ | 量 **5V 对 GND** | ⭐ 同上 |
| ☐ | ⭐ 对照 §2.1 **逐根核对 4 根信号线** | ⭐ **逐根确认**，⛔ 别凭印象 |
| ☐ | 确认左手板**没和 `SDRAM` 模块冲突** | ⚠️ `PMOD`/`SDRAM` 是 **0Ω 二选一** |
| ☐ | 确认 **`PA_EN_n`（`Y14`）悬空**（⭐ 由 FPGA 驱动） | ⚠️ 别外接下拉 |

### ✅ 预期现象

```
⭐ 所有信号线"通"、所有相邻线"不通"
⭐ 3V3/5V 对地电阻都 > 100 Ω（⭐ 几百 Ω ~ 几 kΩ 都正常）
```

---

## 四、⭐⭐ 阶梯验证（⭐ 逐级过，⛔ 别跳级）

> ⭐ **原则**：⭐ **每级都要有"预期现象"** —— ⚠️ **现象不符就停下，⛔ 别继续下一级**。

### 阶梯 1 · 板子活着

| ⭐ 步 | ⭐ 操作 | ⭐ **预期现象** |
|---|---|---|
| 1 | ⭐ 上电（⭐ 12V 或 USB-C） | ⭐ 板上电源灯亮 |
| 2 | ⭐ 观察 `CFG_LED`（`V13`） | ⭐⭐ **绿灯在闪，约 1 Hz** |
| 3 | ⚠️ 若心跳不闪 | 🔴 **停下** —— ⭐ 说明时钟/配置有问题 |

```
⭐⭐ 为什么心跳最重要：⭐ 它是【唯一的"活体见证"】（K-41 的教训）——
   ⭐ 时钟活着 ⇒ 后续才有意义。
```

### 阶梯 2 · I2S 三线（⚠️ 没示波器可跳过）

| ⭐ 测点 | ⭐ **预期现象**（⭐ 实测值，⛔ 不是估计） |
|---|---|
| `HP_BCK`（`Y17`） | ⭐ **3.125 MHz** 方波 |
| `HP_WS`（`AB17`） | ⭐ **48.828 kHz** 方波（⭐ 占空比 50%） |
| `HP_DIN`（`AA16`） | ⭐ **有数据在动**（⛔ 不是恒定电平） |

⚠️ **没有示波器** ⇒ ⭐ **跳过这级**，⭐ 直接听声音。

### 阶梯 3 · ⭐ 听到自检和弦

| ⭐ 步 | ⭐ 操作 | ⭐ **预期现象** |
|---|---|---|
| 1 | ⭐ 上电后**别按键**，安静听 | ⭐⭐ **约 200 ms 后，听到一个和弦** |
| 2 | ⭐ 听音高 | ⭐ **A4（440 Hz）+ C#5（554 Hz）+ E5（659 Hz）**（⭐ A 大调三和弦） |
| 3 | ⭐ 听时长 | ⭐ **约 1 秒后自己停**（⭐ 然后进入安静） |
| 4 | ⭐ 之后 | ⭐ **安静**（⭐ 不再有声音，⛔ 不是一直响） |

```
⭐⭐ 这一级说明：⭐ 合成链（DDS + 波表 + ADSR + 混音 + I2S + DAC）【全通】
   ⇒ ⭐ 这是"出声链"的端到端见证。
```

⚠️ **⚠️ 若【一直响不停】** ⇒ 🔴 已知问题 ⇒ ⭐ 见 §六排查。
⚠️ **⚠️ 若【完全没声】** ⇒ 🔴 **先量 `Y14`**（⭐ `PA_EN_n` 必须【高】）。

### 阶梯 4 · ⭐⭐ 按琴键出声（⭐ **本周硬指标**）

#### ⭐ 前置：确认 `tare` 生效了

| ⭐ 步 | ⭐ 操作 | ⭐ **预期现象** |
|---|---|---|
| 1 | ⭐ 上电后**什么都不按**，等 ~2 秒 | ⭐ `autotare` 跑完（⭐ 16 轴记零点） |
| 2 | ⭐ 此时 `pos` 应该都是 0 | ⚠️ 若不为 0 ⇒ ⭐ 零点没记对 |

#### ⭐ 逐轴测试

| ⭐ 步 | ⭐ 操作 | ⭐ **预期现象** |
|---|---|---|
| 1 | ⭐ **轻按**轴 0（⭐ 按到 ~30%） | ⭐ **听到声音**（⭐ 力度较小） |
| 2 | ⭐ **用力按**轴 0（⭐ 按到底） | ⭐ **声音更大**（⭐ ⚠️ 若"轻重一个样" ⇒ 见 §六） |
| 3 | ⭐ **松开** | ⭐ **声音衰减**（⭐ 约 0.45 秒后静音） |
| 4 | ⭐ 换轴 1、2、3… 逐个试 | ⭐ 每轴都能出声 |

```
⭐⭐ 这一级说明：⭐ 霍尔采集 → 标定 → 事件提取 → 音符管理 → 合成 → 出声【全通】
```

⚠️ **⚠️ 关于"力度"**（⭐ 2026-09-24 修复）：
```
⭐ K-124 修复前：🔴 深阈(1536) > 实际行程(744) ⇒ 力度【恒定】
                  ⇒ ⚠️ 按轻按重一个样（⭐ 而波形全对 ⇒ 极易误判成手感问题）
✅ 修复后：⭐ 深阈按行程比例算 ⇒ ✅ **应该能听出轻重差异**
```

---

## 五、⭐⭐ 串口标定（⭐ 本轮新接通 —— 打字操作）

> ⚠️ **前提**：⭐ §2.3 的 USB-C 线插好。
> ⭐ **打开串口助手**：⭐ 波特率 **1000000**、8N1、⛔ 无流控。

### 5.1 ⭐ 三个命令

| ⭐ 你发 | ⭐ 会发生什么 | ⭐ **预期：串口回什么** |
|---|---|---|
| **`T`** | ⭐ 重新逐轴记零点（16 轴） | ⭐ 先回 **`t`**，⭐ 1~2 秒后回 **`T`**（⭐ 大写 = 全部完成） |
| **`S`** | ⭐ 启动 `span` 标定 | ⭐ 回 **`s`**，⭐ 然后**逐轴回轴号**（⭐ `0`~`9`、`A`~`F`） |
| **`X`** | ⭐ 取消当前标定 | ⭐ 回 **`x`** |

### 5.2 ⭐ `span` 标定操作流程（⭐ 16 轴，照这个走）

> 🔴🔴 **⚠️ 2026-09-24 上板实测：轴号提示【不会回】**（⭐ 见 `K-126`）
>
> ```
> ⭐ 现象：⭐ 发 'S' ⇒ 只收回 's'（受理），🔴 **之后【没有】任何轴号提示**
> 🔴 根因：⭐ calib_span 的 S_PROMPT 只待 1 拍（20 ns）⇒ need_press 是 1 拍脉冲
>         ⚠️ 而 uart_tx 正在发 's'（⭐ 20 µs）⇒ 🔴 **请求被丢，⛔ 不会重发**
> ✅ 但：⭐ **标定本身【能走完】**（⭐ 按顺序盲按即可，⭐ '.'/'!' 回包不撞车）
> ```
>
> ⇒ ⭐⭐ **操作办法：⭐ 盲按**（⭐ 按 `cur_axis` 顺序 0→1→2…）
> ```
> ① ⭐ 发 'S' ⇒ 回 's'
> ② ⭐ 直接按【轴 0】到底、停住 ⇒ ⭐ 预期回 '.'（⭐ 或 '!'）
> ③ ⭐ 再按【轴 1】… 直到回 'D'
> 📌 ⭐ 顺序就是 0→1→2…→15（⭐ 硬件按 `cur_axis` 递推，⛔ 不会跳）
> ```
> ⚠️ **修复计划**：⭐ 加回包 FIFO（⭐ 约 30 min，⭐ 见 `K-126`）—— ⭐ **优先级低于"先出声"**

```
① ⭐ 发 'S'          ⇒ ⭐ 预期：回 's'
② ⭐ 串口回 '0'      ⇒ ⭐ 含义："请把【轴 0】按到底"   ⚠️ **实测不会回（K-126）⇒ 盲按**
③ ⭐ 把轴 0 按到底、⛔ 停住不动（⭐ 等 1~2 秒）
④ ⭐ 成功 ⇒ 回 '.'   失败 ⇒ 回 '!'
⑤ ⭐ 回 '1' ⇒ 换轴 1 …… 直到回 'D'（全部完成）      ⚠️ **实测轴号也不回 ⇒ 按顺序盲按**
```

| ✅ | ⭐ 现象 | ⭐ 含义 / 怎么办 |
|---|---|---|
| ☐ | 回 **`'.'`** | ⭐ 本轴成功 |
| ☐ | 🔴 回 **`'!'`** | ⭐ **本轴被拒** —— ⚠️ "没按到底"或"手没停稳"<br>⇒ ⭐ **重新按稳再试**（⚠️ 最多 8 次） |
| ☐ | 🔴 回 **`'E'`** | ⚠️ 反复失败 ⇒ 放弃 ⇒ ⭐ 重发 `'S'` 重来 |
| ☐ | ⚠️ 发 `'S'` 却回 `'!'` 且没启动 | ⚠️ **上电 200 ms 内** `autotare` 还在跑 ⇒ ⭐ **等一下再发** |
| ☐ | ⭐ 回 **`'D'`** | ⭐⭐ **16 轴全部标定完成** |

⚠️ **两个必须知道的**：
* 🔴 **波特率必须 1000000**（⭐ 选错收到乱码，⛔ 不报错）
* ⚠️ **发命令会让 `evt_uart_rx` 的 `hdr_err_cnt` 涨** —— 🔴 **正常，⛔ 不是故障**

---

## 六、🔴 出问题时的排查顺序

| ⭐ 症状 | ⭐ **最可能的原因** | ⭐ 怎么查 |
|---|---|---|
| 🔴 **完全没声** | ⭐ `PA_EN_n` 低 / ADC 没读到 | ⭐ **先量 `Y14`**（⭐ 必须**高**） |
| 🔴 **一上电就恒响** | 🔴 所有轴被判"按下" | ⭐ `pos` 恒高 ⇒ ⚠️ `tare` 没做 / 极性反了 |
| ⚠️ **读数乱跳** | ⚠️ 40 cm 排线干扰 | ⭐ **把 SPI 降到 500 kHz**（`top.v` 的 `.SCLK_HZ`） |
| ⚠️ **按轻按重一个样** | ⚠️ 力度阈值问题 | ⭐ 已修 `K-124` ⇒ ⭐ 若仍如此，查 `.POS_FULL` 是否匹配实际行程 |
| 🔴 **心跳不闪** | 🔴 烧录失败 / 时钟没起 | ⭐ 重新烧 · ⭐ 示波器量 `V22`（50 MHz） |
| ⚠️ **串口没回话** | ⚠️ 波特率错 / 线没插好 | ⭐ 确认 **1000000** + ⭐ **发单个 ASCII 字符**（⛔ 不是字符串） |

---

## 七、⚠️ 今天【测不到】什么（⛔ 别以为是故障）

| # | ⭐ 项 | ⚠️ 说明 |
|---|---|---|
| **1** | 🔴 **串口灌曲谱** | ⚠️ `evt_uart_rx` **被综合器整个扫掉**（⭐ 输出无消费者）<br>⇒ ⭐ 灌进去**完全无作用**（⭐ 要修得先引调试脚） |
| **2** | ⚠️ **LED / TLC5916** | ⚠️ 本轮未接通 |
| **3** | **节拍器 / 鼓机 / Looper** | ⚠️ 未接入顶层 |
| **4** | **5 个音色槽** | ⚠️ `timbre` 扩位未落地 |

---

## 八、⭐ 记录表（⭐ 每测一项就填，⛔ 别凭记忆）

### 8.1 出发前

| ✅ | 项 | ⭐ 实测 |
|---|---|---|
| ☐ | 构建 exit code | |
| ☐ | `Gowin2026.fs` 时间戳 | |
| ☐ | 器件型号 | |

### 8.2 烧录

| ✅ | 项 | ⭐ 实测 |
|---|---|---|
| ☐ | Programmer 能否扫到器件 | |
| ☐ | 烧录结果（Success / error 数） | |
| ☐ | `CFG_LED` 闪不闪 | |

### 8.3 阶梯验证

| ⭐ 阶梯 | ✅ | ⭐ 实测现象 |
|---|---|---|
| **1 心跳** | ☐ | |
| **2 I2S** | ☐ | `HP_BCK` = ____ · `HP_WS` = ____ |
| **3 自检和弦** | ☐ | 听到没：____ · 时长：____ |
| **4 按琴键** | ☐ | 轴号：____ · 有无力度差异：____ |

### 8.4 逐轴霍尔（⭐ 16 轴，测几个算几个）

| ⭐ 轴 | ✅ | ⭐ 有声音？ | ⭐ 力度有差异？ | ⚠️ 异常 |
|---|---|---|---|---|
| 0 | ☐ | | | |
| 1 | ☐ | | | |
| … | | | | |

---

## 附 · 相关文档

| 想看什么 | ⭐ 去哪 |
|---|---|
| ⭐ **深挖版上机指南** | `bringup/07-Console上机指南-20260924.md` |
| ⭐ 引脚真值（⭐ 权威） | `constr/top.cst` |
| ⭐ Console 引脚查证 | `files/10-硬件/板卡替换评估/Console引脚查证-20260922.md` |
| ⭐ 左手板原理图评审（⭐ 信号座针序） | `files/10-硬件/左手板原理图评审.md` |
| ⭐ 已归档的旧版上机指南 | `files/历史/06-Console上板测试指南-过时-引脚已被09-24重排取代.md` |
