hokuu1102/Gowin2026-PolySynth/bringup/07-Console上机指南-20260924.md

# 🔌 07 · Console 60K 上机指南（**2026-09-24 上板版**）

> **作者**：FPGA 线（甲）
> **日期**：2026-09-23 晚
> **适用**：⭐ **明天（9/24）第一次把 Console 60K 接上左手板**
> **目标**：⭐⭐ **按琴键出声**（⭐ 本周硬指标）
>
> **关联**：`files/历史/06-Console上板测试指南-过时-引脚已被09-24重排取代.md`（⭐ 前一版，⚠️ 引脚已过时）

---

## 〇、⚠️⚠️ 先看这个：**今晚引脚【全变了】**

🔴 **如果你手上有 9/23 白天打印的接线表 ⇒ 作废。** ⭐ 以本文 §2 为准。

| 变化 | 说明 |
|---|---|
| 🔴 **6 根 ADC 全部换 ball** | ⭐ 为了"每片 `MISO`+`CS` 同排左右"（⭐ 扩展板好走线） |
| 🔴 **LED 组从 `PMOD` 挪到 `J9`** | ⭐ 遵守"PMOD 留给高需求"原则 |
| ⭐ **SPI 端口改成 6 片预留** | ⚠️ 但**软件仍只跑 2 片**（⭐ 端口留 6 位、`N_ADC=2`） |

---

## 一、⭐⭐ 三条铁律（⛔ 违反会白忙一夜）

| # | 铁律 | ⚠️ 为什么 |
|---|---|---|
| **1** | ⭐ **每次上电前先量 3V3 和 5V** | 🔴 接错电源会**烧板子**（⭐ 不可逆） |
| **2** | ⭐⭐ **`PA_EN_n`（`Y14`）对 Console 板必须【高】** | 🔴 它接 `MAX98357A` 的 `SD_MODE` ⇒ **低 = Shutdown = 无声**（⭐ `U-25b`）<br>⭐ 而 `top.v` 默认 `PA_ON_AFTER_RESET=1` ⇒ ✅ **默认就是对的** |
| **3** | ⭐ **一次只改一个变量** | 🔴 同时改接线 + 参数 ⇒ 出问题**不知道是谁的** |

---

## 二、⭐⭐ 接线表（⭐ 权威：`constr/top.cst`，⭐ 今晚刚改）

### 2.1 ⭐ 左手板（⭐ 插 `J9`，⚠️ 40P 双排）

#### SPI 组（14 根，⭐ 每片 `MISO`+`CS` **同排左右**）

| `J9` 针 | 信号 | **ball** | ⭐ 接左手板 |
|---|---|---|---|
| **`N1`** | `spi_sclk` | **`E14`** | ⭐ 所有片共享 |
| **`N2`** | `spi_mosi` | **`E13`** | ⭐ 所有片共享 |
| ⭐ **`N3`** | `spi_miso[0]` | **`C15`** | ⭐ **片0（板1）** |
| ⭐ **`N4`** | `spi_cs_n[0]` | **`C14`** | |
| ⭐ `N5` | `spi_miso[1]` | **`B13`** | ⭐ **片1（板2）** |
| ⭐ `N6` | `spi_cs_n[1]` | **`C13`** | |
| ⭐ `N7` | `spi_miso[2]` | **`A14`** | ⭐ **片2（右手板 A）** |
| ⭐ `N8` | `spi_cs_n[2]` | **`A13`** | |
| ⭐ `N9` | `spi_miso[3]` | **`B16`** | ⭐ 片3（预留） |
| ⭐ `N10` | `spi_cs_n[3]` | **`B15`** | |
| ⚠️ **`N11`** | **`+5V`** | — | ⚠️ **板上固定** |
| ⚠️ **`N12`** | **`GND`** | — | ⚠️ **板上固定** |
| ⭐ `N13` | `spi_miso[4]` | **`A16`** | ⭐ 片4（备用） |
| ⭐ `N14` | `spi_cs_n[4]` | **`A15`** | |
| ⭐ `N15` | `spi_miso[5]` | **`A20`** | ⭐ 片5（备用） |
| ⭐ `N16` | `spi_cs_n[5]` | **`B20`** | |

> 🔴 **2026-09-30 更正（⛔ 保留旧结论，不删）**：本表原写「`N13`/`N14` = **片4（右手板 A）**」、
> 「`N7`/`N8` = 片2（预留）」、`N15`/`N16` = 片5（右手板 B）—— ⚠️ **前两条与第三条都已作废**：
> · 🔴 **右手板 A = 【片2】**（⭐ `J9 N7`/`N8`，⭐ ball `A14`/`A13`）—— ⭐ 依据：`rtl/top.v` 取
>   `af_data[2*12]`，且 `ADC_N = 2`（⭐ 只扫片 0/1）；⭐ 而 `N13`/`N14`（`A16`/`A15`）在 RTL 里是 **片4**
>   ⇒ ⚠️ **按旧表接到 `N13`/`N14` ⇒ 接上也没反应**（⭐ 静默不工作）。
> · ⚠️ **右手板 B 现为【通用控制板】**（⭐ 用户 2026-09-30 决定；⭐ 可能做矩阵键盘，**键数与接口待定**）
>   ⇒ ⭐ **本次不分配任何引脚**，🔴 **`OLED` 已取消** ⇒ ⭐ 「片5 = 右手板 B」**作废**（⭐ 片3~片5 = 备用）。
> · ✅ **仍有效的部分**：片0 = 左手板 1（`C15`/`C14`）· 片1 = 左手板 2（`B13`/`C13`）· 共享 `E14`/`E13`。

> ⭐⭐ **今晚只接【片0/片1】两根 `MISO` + `SCLK` + `MOSI` + 【2 个 `CS`】= 6 根**
> ⚠️ 其余 8 根（`N9`~`N16`）**留空** —— 🔴 **但别剪断**，⭐ 以后加板要用。

#### LED 组（8 根，`N17`~`N24`）

| `J9` 针 | 信号 | **ball** | 说明 |
|---|---|---|---|
| `N17` | `led_le` | **`A21`** | ⭐ 共享锁存 |
| `N18` | `led_sdi` | **`B21`** | ⭐ 共享数据 |
| `N19` | `led_clk` | **`B18`** | ⭐ 共享时钟 |
| `N20` | `led_oe_n[0]` | **`B17`** | ⭐ 低有效 |
| `N21` | `led_oe_n[1]` | **`C17`** | |
| `N22` | `led_oe_n[2]` | **`D17`** | |
| `N23` | `led_oe_n[3]` | **`A19`** | |
| `N24` | `led_oe_n[4]` | **`A18`** | |

> ⚠️ **LED 组明天可以先不接**（⭐ `top.v` 还没例化 `tlc5916_driver`，⭐ 属丙线）——
> ⭐ 但**引脚已定**，⭐ 接上也不会有动作（⭐ 输出恒为"全灭"安全态）。

### 2.2 ⭐ 板载固定（⛔ 不用接，⭐ 核对即可）

| 信号 | **ball** | 说明 |
|---|---|---|
| `clk` | **`V22`** | ⭐ 板载 50 MHz |
| `rst_n` | **`AA13`** | ⚠️ **1.5V 域**，板上按键 |
| `HP_BCK` / `HP_WS` / `HP_DIN` | **`Y17` / `AB17` / `AA16`** | ⭐ I2S → `MAX98357A` |
| `PA_EN_n` | **`Y14`** | ⚠️ **1.5V 域**，接 `SD_MODE` |
| `led_heartbeat` | **`V13`** | ⭐ `CFG_LED` 绿路 |

### 2.3 ⚠️ 电源（⭐ 最容易出错的地方）

| 项 | ⭐ 做法 |
|---|---|
| ⭐ **左手板 3V3** | ⭐ 从 `J9` 的 **`N11`/`N12`** 取（⭐ 那是 `+5V`/`GND`）<br>⚠️ **但 `MCP3208` 要 3.3V** ⇒ ⭐ **需确认左手板自带 LDO 还是要从别处取 3V3** |
| 🔴 **⚠️ 先量再插** | ⭐ 万用表量 `J9` 的电源针，⭐ **确认电压对**再插左手板 |
| ⭐ **地线** | ⭐ **多根并联**（⭐ 40 cm 排线，⭐ 单根地会有回流问题） |

---

## 三、⭐⭐ 阶梯 0 · 不上电的检查（⭐ 15 分钟）

| # | ⭐ 检查项 | 判据 |
|---|---|---|
| **1** | ⭐ 万用表量 **3V3 对 GND 的电阻** | ⚠️ **不能是 0**（⭐ 短路）⇒ ⭐ 应 > 100 Ω |
| **2** | ⭐ 量 **5V 对 GND** | 同上 |
| **3** | ⭐ 对照 §2 核对 **6 根 ADC 线** | ⭐ 逐根确认，⛔ 别凭印象 |
| **4** | ⭐ 确认左手板**没有和 `SDRAM` 模块冲突** | ⚠️ `PMOD`/`SDRAM` 是 **0Ω 二选一** |
| **5** | ⭐ 确认 **`PA_EN_n`（`Y14`）悬空**（⭐ 由 FPGA 驱动） | ⚠️ 别外接下拉 |

---

## 四、⭐⭐ 阶梯 1~2 · 板子活着 + I2S 在动（⭐ 30 分钟）

### 4.1 ⭐ 阶梯 1 · 烧录 + 心跳

```powershell
# ⭐ 在仓库根目录
powershell -NoProfile -ExecutionPolicy Bypass -File sim\gowin_build.ps1
# ⇒ ⭐ 产出 impl/pnr/Gowin2026.fs
```

| ⭐ 判据 | ⚠️ 不符怎么办 |
|---|---|
| ✅ **`CFG_LED`（`V13`）在闪**（⭐ ~1 Hz） | 🔴 不闪 ⇒ ⭐ 先查烧录成功没、`clk` 有没有（⭐ 示波器量 `V22`） |

### 4.2 ⭐⭐ 阶梯 2 · I2S 三线（⭐ 示波器）

| 信号 | ⭐ 期望 |
|---|---|
| `HP_BCK`（`Y17`） | ⭐ **~3.07 MHz** 方波（⭐ 50M/16.28） |
| `HP_WS`（`AB17`） | ⭐ **~48 kHz**（⭐ 每 64 个 `BCK` 翻转） |
| `HP_DIN`（`AA16`） | ⭐ 有数据在动 |

⚠️ **没有示波器怎么办**：⭐ **跳过这级**，⭐ 直接听声音（⭐ 下一步）。

---

## 五、⭐⭐⭐ 阶梯 3 · ⭐ **听到自检和弦**（⭐ 关键判据）

### 5.1 ⭐ 会发生什么

```
⭐ 上电 ⇒ 等 ~40 ms ⇒ ⭐ **自动响一个 A4+C#5+E5 和弦**（⭐ 1 秒）⇒ ⭐ 自动停
```

⭐ **这是 `T57` 自检音**（⭐ `DEMO_CHORD_ON=1`）—— ⭐ **它证明整条出声链通了**。

| ⭐ 听到什么 | ⭐ 结论 |
|---|---|
| ✅ **响了 1 秒然后停** | ⭐⭐ **出声链通了** ⇒ ⭐ **继续下一级** |
| ⚠️ **响了但不停** | ⚠️ 检查 `DEMO_HOLD_CYC`（⭐ 应 = 50000000） |
| 🔴 **完全没声** | 🔴 **查 `PA_EN_n`**（⭐ 铁律 2）：⭐ **量 `Y14` 是不是高**<br>⚠️ 低 = `Shutdown`（⭐ `U-25b`） |
| ⚠️ **"啪"一声就没** | ⚠️ 可能是 `PA_ON_DELAY` 问题 |

> ⭐ **提醒**：⭐ 如果你想**跳过自检音**（⭐ 只听手弹），⭐ 可以在 `top.v` 把
> `DEMO_CHORD_ON` 设 0 —— 🔴 **但那样整条合成链都不例化**（⭐ 结构性静音），
> ⚠️ **什么都不会响**。⭐ **所以⛔ 别这么干。**

---

## 六、⭐⭐⭐ 阶梯 4 · ⭐ 按琴键出声（⭐ **本周硬指标**）

### 6.1 ⚠️ 前置：确认 `tare` 生效了

⭐ `top.v` 现在有 **`calib_autotare`**：⭐ 上电等 **200 ms**（`AUTOTARE_DELAY_CLK=10M`）
⇒ ⭐ 逐通道记零点。

| ⭐ 判据 | ⚠️ 不符 |
|---|---|
| ⭐ **松手时 `pos` ≈ 0** | 🔴 若 ≈ 2110 ⇒ ⭐ **`tare` 没生效** ⇒ ⚠️ 检查 `u_autotare` 的 `done_o` |

⚠️ **怎么观测 `pos`？** ⭐ **目前没有引到引脚上**（⭐ 见 §8 待做项）。
⭐ **替代办法**：⭐ **直接听** —— 🔴 **若一上电就"恒响不停"** ⇒ ⭐ **说明所有轴被判"按下"**。

### 6.2 ⭐ 逐轴测试

| # | ⭐ 动作 | ⭐ 期望 |
|---|---|---|
| **1** | ⭐ **按左手板某条磁轴到底** | ⭐ **听到对应音高的音** |
| **2** | ⭐ **松手** | ⭐ **音停**（⚠️ 有 ~0.45 s 尾巴，⭐ 那正常） |
| **3** | ⭐ **按不同的轴** | ⭐ **音高不同** |
| **4** | ⭐ 按第二个板的轴 | ⭐ 也出声 |

### 6.3 🔴 出问题时的排查顺序（⭐ 按可能性）

| 症状 | ⭐ 最可能的原因 | ⭐ 怎么查 |
|---|---|---|
| 🔴 **完全没声** | ⭐ `PA_EN_n` 低 / ADC 没读到 | ⭐ 先量 `Y14` |
| 🔴 **一上电就恒响** | 🔴 **所有轴被判"按下"** | ⭐ 说明 `pos` 恒高 ⇒ ⚠️ `tare` 没做 / 极性反了 |
| ⚠️ **读数乱跳** | ⚠️ **40 cm 排线干扰** | ⭐ **先把 SPI 降到 500 kHz**（⭐ 见 §7） |
| ⚠️ **只有部分轴响应** | ⚠️ 个别 MCP3208 通道坏 / 虚焊 | ⭐ 逐个量霍尔电压 |

---

## 七、⭐⭐ 已知调参旋钮（⭐ 出问题先试这些）

| # | 旋钮 | 位置 | ⭐ 什么时候用 |
|---|---|---|---|
| **1** | ⭐ **SPI 时钟 → 500 kHz** | `top.v` 的 `.SCLK_HZ(1_000_000)` | ⚠️ **读数不稳/乱跳**时<br>⭐ 我们时间余量 **600 倍** ⇒ ✅ 降速无感 |
| **2** | ⭐ **触发/释放阈值** | `.TRIG_TH(12'h095)` / `.REL_TH(12'h059)` | ⚠️ 太灵敏（误触）/ 迟钝（按很深才响） |
| **3** | ⭐ **`tare` 等待时间** | `.AUTOTARE_DELAY_CLK(10_000_000)` | ⚠️ 若 200 ms 不够霍尔稳定 |
| **4** | ⭐ **心跳 LED 频率** | `.HEARTBEAT_DIV(25_000_000)` | ⚠️ 想确认板子活着 |

⚠️ **改完必须重跑 `gowin_build.ps1` + 重新烧录。**

---

## 八、⚠️ 本次**测不到**什么（⛔ 别把"过了"当"都没问题"）

> ⭐⭐ **先看这张表（⭐ 明天上板前必读）** ——
> ⭐ **"模块写完了" ≠ "功能能用了"**：⚠️ 代码在库里，但**没接进 `top.v` 就等于没有**。

### 8.1 ⭐ 明天上板【能看到什么】

| # | 功能 | ⭐ 明天能看到吗 |
|---|---|---|
| **1** | ⭐ **心跳 LED 闪** | ✅ **能** |
| **2** | ⭐ **自检和弦响 1 秒后停** | ✅ **能**（⭐ `DEMO_CHORD_ON=1`） |
| **3** | ⭐⭐ **按琴键出声**（⭐ **本周硬指标**） | ✅ **能**（⭐ 见 §六） |
| **4** | ⭐ 不同轴音高不同 / 松手音停 | ✅ **能** |

### 8.2 🔴 明天【看不到】什么（⚠️ 别以为是故障）

| # | 功能 | 为什么看不到 |
|---|---|---|
| **1** | ~~🔴 **`span` 满行程标定**~~ | ✅⭐ **2026-09-23 阶段C 已接通！** ⇒ ⭐ **现在可用**（⭐ 发 `'S'`，⭐ 见 §8.5） |
| **2** | ~~🔴 **串口发 `'T'`/`'S'`/`'X'` 命令**~~ | ✅⭐ **已接通** —— ⭐ `top.v` 新增 `uart_rx`（`V14`）<br>⚠️ **但需要一根 USB-C 线**（⭐ 见 §8.5） |
| **3** | 🔴 **LED 演奏指引灯** | ⚠️ `tlc5916_driver` 没例化（⭐ 属丙线） |
| **4** | 🔴 **曲谱自动演奏** | ⚠️ `evt_uart_rx` **已例化、能收**，🔴 **但没接进 `evt_merge`**<br>⇒ ⭐ 灌进去也不会响（⭐ 有意为之：一次只改一个变量） |
| **5** | ⚠️ **`pos` 的数值** | ⚠️ 没引到引脚 ⇒ 🔴 **只能靠"听"判断**（⚠️ 见 §6.1） |

### 8.3 ⚠️ 本轮（2026-09-23 深夜）改了什么 —— ⭐ 影响明天上板吗

| # | 改动 | ⚠️ 对上板的影响 |
|---|---|---|
| **1** | ⭐ `calib_span` 修 3 个"静默卡死"缺陷 + 加 `abort_i` | ⚠️ **无影响** —— ⭐ 它**没接进 `top.v`** |
| **2** | ⭐ 新增 `calib_cmd.v` | ⚠️ **无影响** —— 同上 |
| **3** | ⭐ `calib_autotare` 加 `retrig_i` 端口 | ⚠️ **无影响** —— ⭐ 端口接 `1'b0`（⭐ 阶段B 已接）<br>⭐ 行为**与之前完全一致**（⛔ 不重触发） |
| **4** | ⭐ 两个新文件登记进 `.gprj` | ✅ **明天烧的 bitstream 会包含它们**（⚠️ 但**没例化 ⇒ 会被优化掉**，⭐ 不占资源） |
| **5** | ✅⭐ **`calib_span` 已接进 `top.v`（阶段B，2026-09-23 深夜）** | ⚠️ **无功能影响** —— ⭐ 因为 `start_i` 接常量 0 ⇒ **一个 `span` 都不会发**<br>⭐ 同时把 `u_calib0/1` 的 **`busy`/`err` 从空连接改为接出** ⇒ ⚠️ 对行为无影响（⭐ 只是让信号可观测）<br>⭐ 且 `cal_ch` 改成**仲裁**（⭐ `sp_busy ? sp_ch : at_ch`）—— ⚠️ `sp_busy` 恒 0 ⇒ **等价于原来的 `at_ch`** ✅ |

> ✅ **结论**：⭐ **明天上板用的行为，与本轮改动之前【完全一致】**
> ⇒ ⭐ **上板结果不受本轮改动影响**（⭐ 这是一件好事：改动能独立验证）。
> ⚠️ **但 bitstream 确实变了**（⭐ 多了 `calib_span` 的电路 + `cal_ch` 多一级组合选择）
> ⇒ ⭐ **必须重新构建 + 重新烧录**，⛔ 不要用旧的 `.fs`。

### 8.4 ⚠️ 详细清单

| # | 项 | ⭐ 状态 |
|---|---|---|
| **1** | 🔴 **滑音 / 双音** | ⚠️ **结构上恒 0**（⭐ 阶段 2 才做） |
| **2** | 🔴 **`span` 增益标定** | ⚠️ **代码有（`calib_span.v`）+ tb 已补齐（34 条判据全过）**，🔴 **但没接进 `top.v`** + 没有触发入口<br>⭐ **2026-09-23 深夜更新**：⭐ 已修 **3 个"静默卡死"真缺陷**（⭐ `S_SETTLE`/`S_VOTE` 无超时、`S_NEXT` 等不到 `busy`）+ 新增 `abort_i`<br>⚠️ 详见 `files/00-总览/未完成工作总账.md` **§十** |
| **3** | 🔴 **UART 命令** | ⚠️ **`evt_uart_rx` 没接进 `top.v`**<br>⭐ **2026-09-23 深夜更新**：⭐ **命令解析器已就绪** —— 新增 `rtl/w3a/calib_cmd.v`<br>（⭐ `'T'`=逐轴 `tare` / `'S'`=逐轴 `span` / `'X'`=取消）· tb **24 条判据全过**<br>🔴 **但 `top.v` 【当前完全没有 UART 端口】** ⇒ ⭐ 要新增端口 + 改 `.cst`（⭐ ball 已查实：`V14`/`U15`）<br>⚠️ 详见 `files/00-总览/未完成工作总账.md` **§十** |
| **4** | 🔴 **LED 演奏指引** | ⚠️ **`tlc5916_driver` 没例化**（⭐ 属丙线） |
| **5** | 🔴 **曲谱 / ESP32 通路** | ⚠️ **`play_seq` 没接** |
| **6** | ⚠️ **`pos` 的实时观测** | ⚠️ **没引到引脚** ⇒ 🔴 **只能靠"听"** |

---

### 8.5 ⭐⭐ 新增能力：串口标定（⭐ 2026-09-23 阶段C）

> 🔴 **2026-09-30 深夜更正：必须【外接 USB-TTL】到 `J9` 排针（`TX→N26` / `RX→N25`）** ——
> ⭐ **板载 USB-C 的串口走不通**（`BL616` 跑 `TangCore` 私有协议，⛔ 不透传 `T`/`S`/`X`）
> ⇒ ⭐ 原文"插一根 USB-C 线 / ⛔ 不用买 USB-TTL" **已作废**。

⭐ **打开串口助手**（⭐ 波特率 **500000**、8N1 —— ⚠️ ⛔ **不是 1000000**），⭐ 发**单个 ASCII 字符**：

| 你发 | 会发生什么 | ⭐ 串口回什么 |
|---|---|---|
| ⭐ **`T`** | ⭐ 重新逐轴记零点（16 轴） | ⭐ `t`，⭐ 约 1~2 秒后 `T` |
| ⭐ **`S`** | ⭐ 启动 `span` 标定（⭐ **需要你逐个按到底**） | ⭐ `s`，⭐ 然后**逐轴回轴号** |
| ⭐ **`X`** | ⭐ 取消当前标定 | ⭐ `x` |

⭐ **`span` 的操作流程**：
```
① 发 'S'      ⇒ 回 's'
② 回 '0'      ⇒ ⭐ 说明"请把【轴 0】按到底"
③ 把轴 0 按到底、停住不动
④ 成功 ⇒ 回 '.'   失败 ⇒ 回 '!'
⑤ 回 '1'  ⇒ 换轴 1 …… 直到回 'D'（全部完成）
```

🔴 **若一直回 `!`**：⭐ "这一轴没按到底"或"手没停稳"
⇒ ⭐ 按稳一点重试（⚠️ 最多 8 次，之后回 `E` 放弃）。

⚠️ **三个注意**：
* 🔴 **波特率必须选 1000000**（⭐ 选错会收到乱码、⛔ 不报错）
* ⚠️ **上电 200 ms 内发 `'S'` 会被忽略**（⭐ 那时 `autotare` 还在跑）⇒ ⭐ 会回 `!`
* ⚠️ **发命令会让 `evt_uart_rx` 的 `hdr_err_cnt` 涨** —— 🔴 **正常，⛔ 不是故障**

> ⭐ **一句话**：⭐ **明天是"按琴键出声"的验证** ——
> ⚠️ **标定相关的一切（`span`/串口命令）都要等接入 `top.v` 之后**。
> ⭐ 接入方案：`files/20-代码/标定链接入top实施方案-20260923.md`

## 九、⭐ 记录表（⭐ 每测一项就填，⛔ 别凭记忆）

### 9.1 板级

| 项 | 实测 | 判据 | ✅/🔴 |
|---|---|---|---|
| 3V3 电压 | ______ V | 3.2~3.4 | |
| 5V 电压 | ______ V | 4.8~5.2 | |
| 3V3-GND 电阻 | ______ Ω | > 100 | |
| `V13` 心跳 | ______ Hz | ~1 | |
| `BCK` 频率 | ______ MHz | ~3.07 | |
| `WS` 频率 | ______ kHz | ~48 | |
| `Y14` 电平 | ______ V | **高** | |

### 9.2 阶梯验证

| 阶梯 | 内容 | ✅/🔴 | 备注 |
|---|---|---|---|
| **1** | 板子活着（心跳闪） | | |
| **2** | I2S 三线在动 | | |
| **3** | ⭐ **听到自检和弦（1 秒后停）** | | |
| **4** | ⭐⭐ **按琴键出声** | | |
| **4b** | 松手音停 | | |
| **4c** | 不同轴音高不同 | | |

### 9.3 逐轴霍尔（⭐ 16 轴，测几个算几个）

| 轴 | 松手电压 | 按到底电压 | 行程 | 出声? |
|---|---|---|---|---|
| 0 | ____ V | ____ V | ____ V | |
| 1 | | | | |
| … | | | | |

> ⭐ **参照今晚实测**：松手 **1.60 V**、触底 **1.00 V** ⇒ ⭐ 行程 **0.6 V**

---

## 十、⭐⭐ 三个纪律（⭐ 都是本项目踩过的）

| # | 纪律 | ⭐ 来历 |
|---|---|---|
| **1** | ⭐ **"不响" ≠ "坏了"** —— 🔴 **先量电源和 `PA_EN`** | ⚠️ `U-25b`：Console 上 `SD_MODE` 低 = Shutdown，⭐ 而波形全对、就是没声 |
| **2** | ⭐ **一次只改一个变量** | 🔴 同时改多处 ⇒ 出问题无法定位 |
| **3** | ⭐ **改完 RTL 必须重跑 full build** | 🔴 **本项目今晚刚犯过**：改完没编译就往下走 ⇒ 21 个 tb 编译失败 |

---

## 十一、⭐ 明天开工前的检查清单

- [ ] ⭐ `git pull` 拿到今晚的引脚改动（⭐ 6 根 ADC 全换了）
- [ ] ⭐ **重新跑一遍 `gowin_build.ps1`**（⭐ 确认 PnR 过）
- [ ] ⭐ 打印/打开本文 §2 的接线表（⛔ **别用旧的**）
- [ ] ⭐ 万用表 + 示波器（⭐ 可选）备好
- [ ] ⭐ 按 §3 做不上电检查

---

## 附 · 相关文档

| 想看什么 | 去哪 |
|---|---|
| ⭐ 前一版上板指南（⚠️ 引脚已过时） | `files/历史/06-Console上板测试指南-过时-引脚已被09-24重排取代.md` |
| ⭐ 引脚权威来源 | `constr/top.cst` |
| ⭐ `J9`/`J10` ball 映射 | `files/10-硬件/Console排针ball映射-C14结案-20260923.md` |
| ⭐ ESP32 侧串口协议 | ⚠️ **在【另一个仓库】**：`<同级目录>/FPGA2026-esp32/files/20-代码/ESP32侧串口命令格式-给FPGA侧-20260923.md`<br>（⚠️ 本仓库里**没有**它 ⇒ ⛔ 故不做成交叉引用，⭐ 免误报） |
| ⭐ 已知问题清单 | `files/20-代码/已知问题与风险清单.md` |
| ⭐ W3a 语义层设计 | `files/20-代码/W3a采集链语义层设计草案-20260923.md` |
