hokuu1102/Gowin2026-PolySynth/bringup/17-引脚分配-左手板2与右手板-20260930.md

# 📌 引脚分配：**第二块左手板** + **右手板 A**（2026-09-30 · 待上板验证）

> **用途**：⭐ **联调（联机调试）前照这张表接线** —— 左手板 2 / 右手板 A。
> **真值来源**：⭐ `constr/top.cst`（本次已改）｜`rtl/top.v`（本次已改）
> **配套**：`bringup/16-上板操作手册-20260929.md`（左手板 1 的接法）｜`files/10-硬件/右手板方案.md`

---

## 〇、⭐ 一句话

```
⭐ 左手板 2 = ADC【片1】 = J9 N5/N6（⭐ 引脚与 RTL 本来就已接好，⛔ 本次没改，只需接线）
⭐ 右手板 A = ADC【片2】 = J9 N7/N8  ＋ 拨弦 TRIG = PMOD1_IO6/7（⭐ 同样已分配，只需接线）
⭐ 右手板 B = 🔴 **本次不分配任何引脚**（⭐ 板 B 改为通用控制板，⭐ 见 §四）
```

🔴 **一句话结论**：⭐ **ADC/拨弦的引脚早就分配好了** —— ⭐ 本次只做两件事：
① 把**片号映射写清**（⚠️ 旧文档写错，见 §五-①）；② **撤回**早先给右手板 B 分的 10 根脚。

---

## 一、⭐⭐ ADC 片号 ↔ 板 ↔ ball（⭐ 全表）

| 片号 | ⭐ 用途 | `spi_miso[N]` | `spi_cs_n[N]` | `led_oe_n[N]` |
|---|---|---|---|---|
| **0** | ⭐ **左手板 1**（⭐ 今天已接） | `C15`（`J9 N3`） | `C14`（`J9 N4`） | `B17`（`N20`） |
| **1** | ⭐⭐ **左手板 2**（⭐ **本次要接**） | `B13`（`J9 N5`） | `C13`（`J9 N6`） | `C17`（`N21`） |
| **2** | ⭐⭐ **右手板 A**（推子/摇杆/音量） | `A14`（`J9 N7`） | `A13`（`J9 N8`） | ⚠️ 无（板 A 没 LED） |
| **3** | 备用 | `B16`（`N9`） | `B15`（`N10`） | `D17`（`N22`） |
| **4** | 备用 | `A16`（`N13`） | `A15`（`N14`） | `A19`（`N23`） |
| **5** | 备用 | `A20`（`N15`） | `B20`（`N16`） | `A18`（`N24`） |

⭐ **共享信号**：`spi_sclk`=`E14`（`J9 N1`）· `spi_mosi`=`E13`（`J9 N2`）· `led_sdi`=`B21`/`led_clk`=`B18`/`led_le`=`A21`

> ⭐ **`led_oe_n` 的实际用法**（⭐ 以 `rtl/w3c/tlc5916_bank.sv` 为准）：
> `oe[0]`=左手板1 键灯 · `oe[1]`=左手板2 键灯 · `oe[2]`/`oe[3]`/`oe[4]` **备用**。
> ⚠️ `oe[4]`（`A18`）早先是给**右手板 B 的状态灯**留的 —— 🔴 **板 B 现在不分配引脚**
> ⇒ ⭐ 它回到"**备用**"（⭐ 引脚本身已分配，⭐ 只是没有用途）。

---

## 二、⭐⭐ 第二块左手板（左手板 2 = ADC 片1）

> 🔴 **RTL 侧【早就接好了，本次一行没改】**：`top.v` 里 `ADC_N = 2` ⇒ `adc_farm` **已经在扫片1**，
> 轴 8~15 走 `calib1` → `axis_snapshot`（`AXIS_N=16`）→ `event_extract`（`AXIS_N=16`）✅
> ⇒ ⭐ **本次缺的只是"物理接线"**（⭐ 所以这条的交付物是**表 + 上电顺序**，⛔ 不是代码）。

| ⭐ 左手板 2 的 `SPI_1` 针 | 信号 | ⭐ `J9` 针 | ⭐ 网络名 | ⭐ **ball** | 方向 | ⭐ IO 标准 / bank |
|---|---|---|---|---|---|---|
| 7 | `MCP_CLK`（`SCLK`） | ⭐ **`N1`** | `SDRAM0_D0` | ⭐ **`E14`** | 出（共享） | `LVCMOS33` / **BANK1** |
| 3 | `MOSI` | ⭐ **`N2`** | `SDRAM0_D1` | ⭐ **`E13`** | 出（共享） | `LVCMOS33` / **BANK1** |
| 5 | `MISO` | ⭐ **`N5`** | `SDRAM0_D4` | ⭐ **`B13`** | **入** | `LVCMOS33` / **BANK1** |
| 1 | `CS` | ⭐ **`N6`** | `SDRAM0_D5` | ⭐ **`C13`** | 出 | `LVCMOS33` / **BANK1** |
| — | `+5V` | `N11` | `+5V` | — | 电源 | — |
| 2/4/6/8 | `GND` | `N12`（多接几根） | `GND` | — | 地 | — |

⭐ **每板独立的一根"板位选"**（⭐ 键灯用）= `led_oe_n[1]` = ⭐ **`C17`** = `J9 N21`（⭐ 低有效）

### 2.1 🔴 上电顺序（⭐ 否则看起来像"第二块板坏了"）

```
⭐ 片1 未接时，它的 MISO 被 FPGA 内部上拉 ⇒ raw = 4095
⇒ autotare 会把该轴 zero 记成 4095 ⇒ pos ≡ 0（⭐ 今天既不出声、也不误触发）
⇒ ⭐⭐ 必须【先插好左手板 2、再上电】（⭐ 或上电后发串口 'T' 重新记零点）
```

### 2.2 ⭐ 力度跟随已覆盖【全部 16 轴】（⭐ 2026-09-30 改动 · 待上板验证）

⭐ 原"已知限制：**跟随只扫到轴 7**"**已消除** —— `rtl/top.v` 的
`VEL_AXIS_N` **8 → 16**、`VEL_AX_W` **3 → 4**
⇒ ⭐ **两块左手板的配置完全一致**（⭐ 板 2 的键与板 1 一样，**按住时力度跟行程变**）。

⚠️ **代价（⭐ 时序敏感，必须重跑 PnR 核）**：
· ⭐ 单轴刷新率**减半**：⭐ 一轮从 8 拍变 16 拍 ⇒ **164 µs → 328 µs**
  （⭐ 这是"一个 `tick_audio` 只扫一个轴"的固有代价，⭐ 想保住 164 µs 就得多一份
   `pos_to_vel` ＋ 选择器 ⇒ ⭐ 与"浅逻辑"相悖 ⇒ ⛔ 不做）
· ⭐ 逻辑增量很小：⭐ **+1 个 FF**（`vu_ax_r` 3 → 4 位）＋ 选择器 `8 选 1` → `16 选 1`
  （⭐ 12 位宽 ⇒ 多半只多一级 2:1 树）
· 🔴 **`top.v` 里那条 `initial` 守卫已改成"必须扫满"**：⭐
  `VEL_AXIS_N != SYS_AXIS_N` 会打印 `ERROR [top]`（⭐ 不再是 `WARN`）

---

## 三、⭐⭐ 右手板 A（推子 / 摇杆 / 音量 + 拨弦比较器）

> ⭐ **引脚此前已分配**（`constr/top.cst` 里就有），⭐ 本次**只做汇总 + 把冲突写清**。

### 3.1 模拟量 = ⭐ **走 ADC 组（片2）**，⛔ 不是直连 FPGA

⭐ **答"推子走 ADC 还是走 `right_analog_ctrl`"这个问题**：⭐ **两者不是二选一** ——
⭐ **推子 → 板 A 的 `MCP3208` → `adc_farm` 片2 → `right_analog_ctrl`**（⭐ 后者是**下游消费者**）。

| 右手板 A 的 `SPI_1` 针 | 信号 | ⭐ `J9` 针 | 网络名 | ⭐ **ball** | 方向 | ⭐ IO 标准 / bank |
|---|---|---|---|---|---|---|
| 7 | `MCP_CLK` | ⭐ `N1` | `SDRAM0_D0` | ⭐ **`E14`** | 出（共享） | `LVCMOS33` / **BANK1** |
| 3 | `MOSI` | ⭐ `N2` | `SDRAM0_D1` | ⭐ **`E13`** | 出（共享） | `LVCMOS33` / **BANK1** |
| 5 | `MISO` | ⭐ **`N7`** | `SDRAM0_D6` | ⭐ **`A14`** | **入** | `LVCMOS33` / **BANK1** |
| 1 | `CS` | ⭐ **`N8`** | `SDRAM0_D7` | ⭐ **`A13`** | 出 | `LVCMOS33` / **BANK1** |

⭐ **通道映射（⭐ `右手板方案.md` §10.3）**：`CH0`=摇杆 · `CH1`=音量 · `CH2`=颤音深度 · `CH3`=颤音速率 · `CH4~7`=接 `AGND`

🔴 **必须把 `top.v` 的 `RIGHT_ADC_ENABLE` 置 1 才生效**（⭐ 当前默认 **0**，⭐ 本次**保持 0**）。
🔴🔴 **⚠️ 板 A 没接好之前⛔ 不要置 1**：⭐ 悬空 `MISO` 被上拉 ⇒ 满量程
⇒ ⭐ 颤音被当成"深度/速率拉满"（⭐ `tb/w3b/tb_vibrato_top.sv` 正是按这个行为建的）。

### 3.2 拨弦比较器 `TRIG_1`（`LM393` 开漏 + 10 kΩ 上拉 ⇒ 越阈为**高**）

| ⭐ 信号 | ⭐ 物理脚 | ⭐ 网络名 | ⭐ **ball** | 方向 | ⭐ IO 标准 / bank |
|---|---|---|---|---|---|
| `TRIG_UP` | `PMOD1_IO6` | `ds_clk` | ⭐ **`E21`** | 入 | `LVCMOS33` / **BANK2** |
| `TRIG_DN` | `PMOD1_IO7` | `ds_clk2` | ⭐ **`D21`** | 入 | `LVCMOS33` / **BANK2** |

⭐ 已由 `rtl/w3a/async_pluck_capture.v` 消费（⭐ 上升沿 + 不应期 2.5 M 拍 ≈ 50 ms）。
⚠️ **板 A 没有按键、没有 LED**（⭐ `右手板方案.md` §一 "⛔ 不放"）⇒ ⭐ **无其它信号**。

---

## 四、🔴 右手板 B —— 本次【不分配任何引脚】

> 🔴 **板 B 改为【通用控制板】**（⭐ 用户决定，2026-09-30）：
> ⭐ 可能做**矩阵键盘**，⚠️ **键数与接口待定** ⇒ ⭐ **暂不分配引脚**；🔴 **`OLED` 已取消**。

⚠️ **2026-09-30 早先那一版曾给板 B 分过 10 根**（OLED 控制 ×3 + 4 按键 + 编码器 ×3，
`J9` 的 `N27`~`N39`）⇒ ⭐ **已全部撤回** ——
⭐ `constr/top.cst` 与 `rtl/top.v` 里**看不到** `oled_*` / `rb_*` 的任何痕迹（⭐ 连端口都没有）。

📌 **等键数/接口定下来再单独分配**。⭐ 届时要**重新核**：
· `BANK` 与电平（⭐ 这次原打算用的 `N27`~`N40` 跨 `BANK1`/`BANK2`，⭐ 两个都是 3.3 V）；
· `J9` 的脚与 `SDRAM` 模块**二选一**（`0Ω` 电阻，⭐ 既有约束）；
· 矩阵键盘要**按行列数**重新算脚数（⚠️ 与"每键一根"完全不同）。

---

## 五、🔴🔴 本次遵守的约束（⭐ 逐条对照）

| # | ⭐ 约束 | ⭐ 本次怎么做 |
|---|---|---|
| **1** | ⛔ **JTAG 四根不动** | `TMS=T13` / `TDO=U13` / `TCK=V12` / `TDI=R13`（`BANK12`）⭐ **一行未碰** ✅ |
| **2** | ⛔ **已用引脚不移动** | ⭐ `git diff` 显示 `constr/top.cst` 的变化**全部集中在"撤回板 B"与注释**上，⭐ 已有引脚（SPI/LED/UART/PMOD）**一条没动** ✅ |
| **3** | ⚠️ **bank/电压冲突必须点名** | 🔴 **`BANK9` = 1.5 V**（`rst_n=AA13` / `PA_EN_n=Y14` / `timbre_btn_i=AB13`）⭐ **本次一个都没碰** ✅<br>📌 `BANK2` 的 3.3 V 由 `I2S2_*`（`F20`/`E22`/`D22`）**已在板上跑通**确认 ✅ |
| **4** | ⚠️ **`J9` 的脚 ⇒ 不能插 `SDRAM` 模块** | ⭐ 既有约束（`0Ω` 二选一），⭐ 本次沿用（⭐ 我们不用 SDRAM） |
| **5** | ⚠️ **`DRIVE` 只给输出脚** | ⭐ 输入脚只写 `IO_TYPE`/`PULL_MODE`/`BANK_VCCIO`，⛔ 不带 `DRIVE`（⭐ 避免 `CT1108`）✅ |

### 5.1 🔴 需要更正的文档（⭐ 本次⛔ 不改 `files/**`，留给上级）

| 文档 | 现在写的 | 应为 |
|---|---|---|
| `files/10-硬件/排线采购-最终形态-20260923.md` §6.3 | 片0~3 = 左手板 1~4；片4 = 右手板 A | ⭐ **片0=左手板1 · 片1=左手板2 · 片2=右手板A · 片3~5=备用** |
| `bringup/07-Console上机指南-20260924.md` §2.1 | `N13` 片4（右手板 A） | ⭐ **右手板 A 在 `N7`/`N8`（片2）** |
| `files/20-代码/已知问题与风险清单.md` `K-141` | "`top.cst` 是 GBK 编码" | ⚠️ **实测是 UTF-8 无 BOM + LF**（⭐ `K-141` 的编码判断有误） |

---

## 六、⚠️ 待用户确认（⭐ 我没有替他拍板的地方）

| # | ⭐ 问题 | ⭐ 本次的默认做法 | ⚠️ 影响 |
|---|---|---|---|
| **①** | ⭐ **右手板 A 的 ADC 组号**：**片2**（RTL 现状）还是**片4**（旧文档）？ | ⭐ **片2**（`J9 N7/N8`）—— ⭐ 理由：16 轴 = 2 块左手板 ⇒ 片2 本来就空；⭐ RTL 早已按片2 实现 | 🔴 **按旧文档接到 `N13/N14` ⇒ 接上也没反应** |
| **②** | ⭐ `RIGHT_ADC_ENABLE` 默认要不要改成 **1**？ | ⭐ **保持 0** —— ⚠️ 否则今天"只有左手板"的机器会**颤音拉满** | ⭐ 要联调右手板 A ⇒ ⭐ **改 1 后重跑 PnR** |
| **③** | ⭐ 板 B 的**键数与接口**（⭐ 矩阵键盘的行列数 / 是否需要编码器 / 是否还要显示） | ⭐ **暂不分配引脚**（⭐ 键数未定 ⇒ 分了也要全改） | ⚠️ 定下来后要**单独**分配一轮，⭐ 并重新核 `BANK`/电平/`SDRAM` 二选一 |

---

## 七、📌 本次改动清单

| 文件 | 改了什么 |
|---|---|
| `constr/top.cst` | ⭐ **撤回**早先给右手板 B 的 **10 条 `IO_LOC`/`IO_PORT`**（⭐ 已有引脚一条没动）<br>⭐ 保留并更正**片号映射注释**（片2 = 右手板 A）＋ 左手板 2 的接线/上电顺序注释<br>⭐ "右手区"整段保留（⭐ 只留**板 A**），⭐ 板 B 改成"**不分配引脚 / OLED 已取消**"的说明 |
| `rtl/top.v` | ⭐ **撤回**右手板 B 的 **10 个顶层端口**（`oled_res_n_o`/`oled_dc_o`/`oled_cs_n_o` ＋ `rb_key1..4_i`/`rb_enc_a/b/sw_i`）＋ 其"安全空闲态 / Z-safe 同步"逻辑 ⇒ ⭐ `led_data.status_i` **回到占位 `8'd0`**<br>⭐ ⭐ **`VEL_AXIS_N` 8 → 16**、`VEL_AX_W` 3 → 4（⭐ +1 FF ＋ 选择器多一级）⇒ ⭐ **两块左手板的力度跟随配置一致**（⭐ 待上板验证）<br>⭐ `initial` 守卫：⭐ `WARN`（允许只扫一部分）→ **`ERROR`（必须扫满）** |
| `tb/w3b/tb_vel_top_stream.sv` | ⭐ 8 轴判据**全部改 16 轴**（⭐ 轮转 / 包数 / `as_pos` 强制位宽）＋ **新增 ⑩ 段**：⭐ 只抬**轴 8~15** ⇒ ⭐ 必须恰好 8 个包且轴号 ∈ [8,15] |
| `tb/w3c/tb_looper_tail.sv` | ⭐ 本地 `vu_*` 激励模型同步改成 **16 轴**（⭐ 否则"逐字同式"这句话是假的） |
| `bringup/17-…（本文件）` | ⭐ 片号映射写清 · ⭐ **删掉板 B/OLED 章节**（⭐ 改为"不分配引脚"）· ⭐ 2.2 节改成"跟随已覆盖 16 轴" |

---

## 附 · 出处（⭐ 逐条可查）

| 事实 | ⭐ 出处 |
|---|---|
| `J9` 的 `N1`~`N40` 逐针**网络名** | ⭐ Console 原理图第 8 页 `EX CONN.`（⭐ 提取副本 `build/console_extract/console_netlist.txt`） |
| **网络名 → ball** | ⭐ 同一份提取的 SOM_BTB 引脚表（⭐ 例：`BANK1_D16_IOT87B = SDRAM0_~{WE}`） |
| `sdram_adr[*]` / `sdram_ba[*]` 复核 | ⭐ `files/开发板原理图/tang_mega_60K_pins.cst`（官方约束） |
| `PMOD1_IO6/7` = `E21`/`D21` | ⭐ `files/10-硬件/开发板与引脚资料.md`（`BANK2_E21_IOT138A` / `BANK2_D21_IOT138B`） |
| 板 A/板 B 的信号清单与上拉 | ⭐ `files/10-硬件/右手板方案.md` §一/§二/§9/§10 |
| 16 轴 = 2 块左手板 | ⭐ `files/10-硬件/霍尔键位-CH映射-20260923.md` §〇 |
| `ADC_N` / `RIGHT_ADC_ENABLE` / `VEL_AXIS_N = 16` | ⭐ `rtl/top.v` |
