hokuu1102/Gowin2026-PolySynth/bringup/15-上机-90分钟最高效率-20260926.md

# ⏱️ 上机 90 分钟最高效率指南（⭐ 2026-09-26 深夜）

> 🔴 **2026-09-29 更新：⭐ 本指南已被 `bringup/16-上板操作手册-20260929.md` 取代**
> ⇒ ⭐ **那份才是当前唯一照做版** ✅
> ⚠️ **本指南【两处已过时】**：
> ① 🔴 **外置 DAC 的 `MSB_DELAY` 现在是 `0`**（⭐ 2026-09-26 上板**实测出声**）
>    ⇒ ⚠️ **⛔ 别按本指南 §二 把它改成 `1`**（⭐ 板载 `MAX98357A` 才是 `1`，⭐ 两路**故意不同**）✅
> ② ⚠️ 本指南的 `.fs` 是 **09-26** 那版 ⇒ ⭐ **现在应烧 `impl/pnr/Gowin2026.fs`（⭐ 2026-09-29 03:45）** ✅
> 📌 本指南的**时间分配**与**外置 DAC 接线表**仍然有效 ✅

> **前提**：⭐ 只有 **~90 分钟**
> **目标**：⭐ **按性价比排序**，⭐ 每一分钟都花在"能改变结论"的测量上
> **本版 `.fs`**：⭐ `impl/pnr/Gowin2026.fs`（⭐ `2026/9/26 01:42:28`，⭐ **含全部 6 个修复**）

---

## 〇、⭐⭐ 一句话

```
⭐ **必须烧新 `.fs`**（⭐ 旧版有削顶 + 时序不达标）
⭐ **核心就两件事**：① 确认削顶好了没 ② 用示波器抓 `LRCK` vs `DIN` 的位对齐
```

---

## 一、🔴 先烧写（⭐ 3 分钟）

```powershell
cd C:\Users\hokuu\Desktop\FPGA\FPGA2026

& "C:\Gowin\Gowin_V1.9.12.03_x64\Programmer\bin\programmer_cli.exe" `
  --device GW5AT-60B `
  --fsFile "C:\Users\hokuu\Desktop\FPGA\FPGA2026\impl\pnr\Gowin2026.fs" `
  --operation_index 1 `
  --cable "USB Debugger A"
```

⚠️ **`--operation_index 1`** = 烧写（⭐ `0` 只读 ID，⭐ 看着成功但没烧）
⚠️ **`.fs` 是 SRAM 配置 ⇒ 断电就丢 ⇒ 先烧再听**

### ⭐ 为什么必须烧新的

| ⭐ 修复 | ⭐ 旧版 | ⭐ **本版** |
|---|---|---|
| 复音削顶 | 🔴 削顶 **28.7%** | ✅ **贴顶率 0.0%** |
| 时序 | 🔴 Fmax **39.5**（⭐ 不达标） | ✅ **51.146 MHz** |
| 音高 | ⚠️ 按轴号乱序 | ✅ 按物理位置 |
| 事件对齐 | ⚠️ 差一拍 | ✅ 已对齐 |
| 节拍器 | 🔴 1.7 Hz 闷响 | ✅ **1760/880 Hz** |
| 迟滞 | ⚠️ 60（⭐ 反复） | ✅ **112** |

---

## 二、⭐⭐ 最高优先：**示波器抓位对齐**（⭐ 20 分钟）

> 🔴 **这是本次上机【唯一能定性】"低频小 + 失真"的测量。**
> ⭐ 因为仿真止于 `sample_mono`，⭐ **其他 9 条假设都排除了** ⇒ ⭐ **只剩这一条没测**。

### ⭐ 接法

| ⭐ 探头 | ⭐ 接到 |
|---|---|
| **CH1** | ⭐ `I2S2_LRCK`（⭐ 引脚 **`E22`**） |
| **CH2** | ⭐ `I2S2_DIN`（⭐ 引脚 **`D22`**） |
| ⭐ 触发源 | ⭐ **CH1**，⭐ **下降沿**（⭐ = 左声道起点） |
| ⭐ 时基 | ⭐ **~2 µs/格**（⭐ 一帧 20.48 µs） |
| ⭐ 地夹 | ⭐ 接 GND |

### 🔊 **播放内容**：⭐ 让它**持续响一个低音**

⭐ **问题**：⭐ 自检和弦只响 **1 秒**（⭐ 且是 A4/C#5/E5 高频），⭐ **不是低频**。

📌 **⇒ 用【按键】制造持续低音**：
```
⭐ 上电 → 等 1 秒（⭐ 自检和弦响完）→ ⭐ **按住一个琴键不放**
⇒ ⭐ 那个键会持续发声（⭐ A2=110Hz 或 D3=147Hz）
```

### 🔴 判据（⭐ 关键）

```
⭐ 标准左对齐（⭐ PCM5102A 的 `FMT`=3V3 时应如此）：

   LRCK:  ‾‾‾‾‾|________|‾‾‾‾‾‾        ← 下降沿 = 左声道数据开始
   DIN :  ------|X X X X X X X X|----  ← ⭐ 数据必须【紧贴】下降沿开始
                ↑
                ⭐ 第 1 个 BCK 就该有数据

🔴 若 DIN 在下降沿后【空了 1 个 BCK】才开始
   ⇒ 🔴 **位对齐差 1 位** ⇒ ⭐ **这就是"低频小 + 失真"的根因！**
```

### ⭐ 若确认差 1 位 ⇒ **改法**

```
⭐ `top.v` 的 `u_i2s_tx_ext` 的 `.MSB_DELAY (0)` 改成 `(1)`
   ⇒ ⭐ 一行改动 ⇒ ⭐ 重跑 PnR（⭐ ~10 分钟）⇒ ⭐ 再烧
⚠️ 但注意：⭐ 你实测过 `MSB_DELAY=1` **完全没声**（⭐ `dac_tone` 三档实测定案）
   ⇒ ⚠️ **若真差 1 位又"改不得"，⭐ 说明问题在别处**（⭐ 先记录下来）
```

---

## 三、⭐ 次优先：**确认削顶好了没**（⭐ 10 分钟）

⭐ **这是本轮改动的主目标**，⭐ 一定要听。

### ⭐ 步骤

| ⭐ 序 | ⭐ 动作 | ⭐ 判据 |
|---|---|---|
| **1** | ⭐ **上电** | ⭐ 听**自检和弦**（⭐ A4+C#5+E5，⭐ 响 1 秒） |
| **2** | ⭐ **按一个键** | ⭐ 单音是否**干净、能听出音高** |
| **3** | ⭐ **同时按 3~4 个键** | 🔴 **是否还"破/糊"** |
| **4** | ⭐ 松手 | ⭐ 是否**干净静音** |

### 🔴 判据

| ⭐ 现象 | ⭐ 结论 |
|---|---|
| ✅ **4 键也干净** | ⭐ **削顶彻底修好** ✅ |
| 🔴 **还是破** | ⚠️ 记录"几个键开始破" ⇒ ⭐ 我再调归一化 |
| ⚠️ **单音偏轻** | ⭐ 正常（⭐ 基准 70 ⇒ 单音 50%）⇒ ⭐ 可提到 80 |

---

## 四、⚠️ 第三优先：**5 分钟快检**（⭐ 若有余力）

| ⭐ 序 | ⭐ 动作 | ⭐ 判据 |
|---|---|---|
| **1** | ⭐ **量模块 `OUTL` 交流幅度**（⭐ 示波器，⭐ 按住键时） | ⭐ 应有**几 Vpp**；🔴 很小 ⇒ DAC 输出级问题 |
| **2** | ⭐ **`FLT` 从 GND 改接 3V3**（⭐ 断电改，⭐ 只这一根） | ⭐ 低频是否变化 |
| **3** | ⭐ **对比板载喇叭**（⭐ 若可用） | ⭐ 板载正常 ⇒ 更锁定外置那路 |
| **4** | ⭐ 量 **`VIN`** 是不是 **5V** | 🔴 ⛔ 别接 3.3V |

---

## 五、⭐⭐ 时间分配（⭐ 按性价比）

| ⭐ 时段 | ⭐ 内容 | ⭐ 为什么这个顺序 |
|---|---|---|
| **0–5 min** | ⭐ 烧写 + 接线检查 | ⭐ 不烧新 `.fs` 后面全白费 |
| **5–15 min** | ⭐ **听：单音 / 4 键 / 松手** | ⭐ **10 分钟就能确认"削顶修好没"**（⭐ 本轮主目标） |
| **15–35 min** | ⭐⭐ **示波器抓 `LRCK` vs `DIN`** | ⭐ **唯一能定性"低频失真"的测量** |
| **35–50 min** | ⭐ 听：音高对不对 / 节拍器 / 触发反复 | ⭐ 验证其余 3 个修复 |
| **50–70 min** | ⭐ 5 分钟快检（⭐ `OUTL` 幅度、`FLT`、板载对比） | ⭐ 给"低频问题"补充证据 |
| **70–90 min** | ⭐ 记录 + 拍照 | ⭐ **证据比结论重要** |

---

## 六、🔴 接线（⭐ 照这张，⛔ 别凭直觉）

| ⭐ 模块丝印 | ⭐ 接到 | ⚠️ |
|---|---|---|
| `VIN` | **5V** | 🔴 **不是 3.3V**（⭐ 模块有 `MIC5219` LDO） |
| `GND` | GND | ⭐ 共地 |
| `LCK` | **`E22`** | ⚠️ **三根挨着，逐根对** |
| `DIN` | **`D22`** | ⚠️ 同上 |
| `BCK` | **`F20`** | ⚠️ 同上 |
| `SCK` | **GND** | 🔴 **必须接地**（⭐ 内部 PLL 要求） |
| `XSMT` | **3V3** | 🔴 **低 = 软静音** |
| `FMT` | **3V3** | ⭐ = 左对齐 |
| `FLT` / `DEMP` | GND | ⭐ 本次可试 `FLT`→3V3 |

### ⚠️ 丝印陷阱（⭐ 上次三根全错）

```
🔴 模块丝印只标 6 个脚（VIN/GND/LCK/DIN/BCK/SCK）
⚠️ 而排针 JP1 实际有 11 个脚
   （11/10 VCC · 9 GND · 8 FLT · 7 DEMP · 6 SCK · 5 BCK · 4 DIN · 3 LRCK · 2 FMT · 1 XSMT）
⇒ 🔴 **FLT/DEMP/FMT/XSMT 是【没标注】的**
⭐ **务必先确认 1 脚位置（方形焊盘），按丝印名逐根接**
```

---

## 七、⭐ 复位与等待

| ⭐ 项 | ⭐ 值 |
|---|---|
| **复位键** | ⭐ **`AA13`**（⭐ Console 板上那个复位按钮） |
| ⚠️ 别按 | ⭐ **`Y12`**（⭐ 那是 `Key_in[1]`，⛔ 不是复位） |
| ⭐ 上电后 | ⭐ **等 > 200 ms** 再按键（⭐ `at_done` 门控） |
| ⭐ 自检和弦 | ⭐ 只响 **1 秒** ⇒ ⭐ **复位后立刻听** |

---

## 八、📋 请带回这些（⭐ 按重要性）

| ⭐ # | ⭐ 要带回的 |
|---|---|
| **1** | ⭐⭐ **示波器照片**：`LRCK` + `DIN` 同屏（⭐ 触发在 `LRCK` 下降沿） |
| **2** | ⭐ **听感结论**：⭐ 单音 / 4 键 是否还破 |
| **3** | ⭐ 音高对不对（⭐ 下排 A2→C3，⭐ 上排 D3→F3） |
| **4** | ⭐ 节拍器听感 |
| **5** | ⭐ `OUTL` 幅度（⭐ 若量了） |

---

## 九、⚠️ 若时间不够（⭐ 只做这两件）

```
⭐ ① 烧 `.fs`  ⇒ ⭐ 听单音 + 4 键  ⇒ ⭐ **确认削顶修好没**（⭐ 10 分钟）
⭐⭐ ② 示波器抓 `LRCK` vs `DIN`   ⇒ ⭐ **定性低频失真**（⭐ 20 分钟）
```

⭐ **这两件事做完，⭐ 就能决定下一步怎么修** —— ⭐ 其余都是加分项。

---

## 十、📌 关联

| ⭐ 想看什么 | ⭐ 去哪 |
|---|---|
| ⭐ 接线速查卡 | `files/10-硬件/接线速查卡-20260926.md` |
| ⭐ 低频问题分析 | `files/10-硬件/外置DAC低频小失真-分析-20260926.md` |
| ⭐ 全量接线表 | `files/10-硬件/外置DAC模块接线表-20260926.md` |
| ⭐ 前一份上机指南 | `bringup/14-上机-优先验证出声-20260926.md` |
