hokuu1102/Gowin2026-PolySynth/bringup/14-上机-优先验证出声-20260926.md

# 🔊 上机指南 · 优先验证「能否出声」（2026-09-26）

> ⭐ **本文专治一件事**：⭐ **让板子出声** —— ⭐ 从零到"听到声音"的最短路径
> **依据**：⭐ 所有参数从 `rtl/top.v` / `constr/top.cst` **实测读出**，⛔ 不凭记忆
> **bitstream**：⭐ `impl/pnr/Gowin2026.fs`（⭐ **2026-09-24 23:40:27**）

---

## 〇、⭐⭐ 结论先说：**可行，而且这是最合适的第一件事**

| ⭐ 判据 | ⭐ 实测 | ⭐ 结论 |
|---|---|---|
| ⭐ `DEMO_CHORD_ON` 默认 | ⭐ **1** | ✅ **一上电就自动响 1 秒三音和弦**（A4+C#5+E5） |
| ⭐ `PA_ON_AFTER_RESET` 默认 | ⭐ **1** | ✅ Console 上 = **`SD_MODE` 拉高 = 出声** |
| ⭐ 出声链 6 个模块 | ⭐ **全在综合报告里** | ✅ `note_manager`/`oscillator_bank`/`tdm_render_mixer`/`master_mix`/`i2s_tx`/`wavetable_bank` |
| ⭐ 外置 DAC 三脚 | ⭐ `F20`/`E22`/`D22` 已约束 | ✅ 两路并存 |

⇒ ⭐⭐ **不需要串口、不需要按键、不需要任何命令** ——
⭐ **只要烧进去，板子自己就会响一声** ⇒ ⭐ **这是最简单的"整链通了"证据**。

---

## 一、⭐⭐ 最短路径（⭐ 3 步，⛔ 不用串口）

### ⭐ 步骤 1：烧板

```powershell
cd C:\Users\hokuu\Desktop\FPGA\FPGA2026

& "C:\Gowin\Gowin_V1.9.12.03_x64\Programmer\bin\programmer_cli.exe" `
  --device GW5AT-60B `
  --fsFile "C:\Users\hokuu\Desktop\FPGA\FPGA2026\impl\pnr\Gowin2026.fs" `
  --operation_index 1 `
  --cable "USB Debugger A"
```

| ⭐ 判据 | ⭐ 期望 |
|---|---|
| ⭐ 输出 | ⭐ `Operation "Reprogram" for device#1...` + ⭐ **`Finished.`** |
| ⭐ exit | ⭐ **0** |

⚠️⚠️ **两个坑**
```
🔴 `--operation_index 1` 才是【烧写】；⭐ `0` = "读 ID"（⚠️ 看着也成功但没烧）
🔴 `--fsFile` 必须【绝对路径】（⭐ 相对路径报 No such file）
```

### ⭐ 步骤 2：上电/复位后**听**

```
⭐ 板子上电（⭐ 或按复位）⇒ ⭐ **约 40 ms 后自动响一个三音和弦**
⭐ 持续 **1 秒** ⇒ ⭐ 然后**自动停**（⭐ 不会一直响）
```

📌 **它响的就是**：⭐ `A4 (440 Hz) + C#5 (554 Hz) + E5 (659 Hz)` ——
⭐ 仿真里 FFT 实测过（⭐ `tb_top_sound`：三个音的能量都 >> 非目标频点）。

### ⭐ 步骤 3：判据表

| ⭐ 现象 | ⭐ 结论 | ⭐ 下一步 |
|---|---|---|
| ✅ **听到"叮"一声和弦**（约 1 秒） | ✅⭐ **整条出声链在真硅片上通了** | ⭐ 可以往下做别的验证了 |
| 🔴 **完全没声** | 🔴 出声链有问题 | ⭐ 见 §三 排查 |
| ⚠️ **有"啪"声但没和弦** | ⚠️ 可能是 `PA_EN` 时序 | ⭐ 见 §三-③ |
| ⚠️ **持续响不停** | ⚠️ 与预期不符 | ⭐ 见 §三-④ |

---

## 二、⭐ 想听更多？两个选择

### 选项 A：⭐ **听外置 DAC**（⭐ 模块已到货）

| ⭐ FPGA 信号 | ⭐ ball | ⭐ `PMOD1` | ⭐ 接 `PCM5102A` |
|---|---|---|---|
| ⭐ `I2S2_BCK` | ⭐ **`F20`** | ⭐ `IO3` | ⭐ BCK |
| ⭐ `I2S2_LRCK` | ⭐ **`E22`** | ⭐ `IO4` | ⭐ LRCK |
| ⭐ `I2S2_DIN` | ⭐ **`D22`** | ⭐ `IO5` | ⭐ DIN |

⭐ **另外必须接**：⭐ 模块 `VIN` → **3.3 V**、⭐ `GND` → GND。

🔴🔴 **三条硬警告（⛔ 违反会烧/没声）**
```
① 🔴🔴 **⛔ 绝对不要接板载 `J5`** —— ⭐ 它是 BTL 输出，⚠️ **接有源音箱会烧**
② 🔴 **模块必须带【板载晶振】** —— ⭐ 靠它从 BCK 恢复时钟；⛔ 没晶振 ⇒ 没声/爆音
③ ⚠️ 接音箱的 **`Line In`**（⛔ 不是功放/BTL 输入）
```

⭐ **判据**：⭐ **外置与板载【同时】出声**（⭐ 两路并存）。

📌 **最省事的判别法**：⭐ **板载有声、外置没声** ⇒ ⭐ **问题在外置接线/模块**
（⭐ 因为两路信号在仿真里**逐拍完全相同** —— ⭐ 实测 `I2S2_DIN 翻转 21202 拍`）。

### 选项 B：⚠️ **听鼓机**（⭐ 需要重新编译）

```
🔴 **默认 `SEL_DRUM=0` = 节拍器** ⇒ ⭐ **当前 bitstream 里【没有鼓机】**
   （⭐ 综合时被优化掉了 —— ⭐ 这是编译期二选一的正常结果）
```
⭐ 要听鼓机 ⇒ ⚠️ **改 `top.v` 参数重新烧**（⭐ 我可以帮你出这个 bitstream）。

---

## 三、🔴 没声时的排查（⭐ 按顺序）

### ① ⭐ 先确认"烧进去了"

```powershell
# ⭐ 读器件状态（⛔ 不烧写，只看）
& "C:\Gowin\Gowin_V1.9.12.03_x64\Programmer\bin\programmer_cli.exe" `
  --device GW5AT-60B --fsFile "<绝对路径>\impl\pnr\Gowin2026.fs" `
  --operation_index 0 --cable "USB Debugger A"
```
| ⭐ 判据 | ⭐ 含义 |
|---|---|
| ⭐ `User Code` **≠ `0xFFFFFFFF`** | ✅ **FPGA 里有配置** |
| ⭐ `User Code` **= `0xFFFFFFFF`** | 🔴 **没烧进去** ⇒ ⭐ 重烧 |

### ② ⭐ `.fs` 是 SRAM 配置 —— **断电就丢**

```
🔴 **板子断过电 ⇒ FPGA 是空的** ⇒ ⚠️ **必须重烧**
📌 尤其：⭐ 昨天用过、今天刚上电 ⇒ ⭐ **先烧板再看现象**
```

### ③ ⚠️ `PA_EN`（⭐ 板载功放的使能）

```
⭐ 它接板载 `MAX98357A` 的 `SD_MODE`
⭐ Console 上 **高 = 出声**（⭐ 与旧板 NEO Dock 相反 —— ⭐ 这是 `U-25b` 的更正）
⭐ 当前 `PA_ON_AFTER_RESET = 1` ⇒ ⭐ **复位后就拉高** ⇒ ✅ 应该有声
🔴 若无声 ⇒ ⭐ 先用万用表量 `Y14` 是不是高
```

### ④ ⚠️ 其他

| ⭐ 检查 | ⭐ 判据 |
|---|---|
| ⭐ 喇叭/耳机接对了吗 | ⭐ Console 板载音频输出口 |
| ⭐ 音量 | ⭐ 若走外置 DAC ⇒ ⭐ 音箱音量 |
| ⭐ 复位 | ⭐ 按一下复位键 ⇒ ⭐ 自检和弦会**重新响一次** |

---

## 四、⭐⭐ 出声验证之后（⭐ 优先级顺序）

| ⭐ 顺位 | ⭐ 验什么 | ⭐ 需要什么 |
|---|---|---|
| **2** | ⭐ **按键出声**（⭐ 手弹链） | ⭐ 左手板 + SPI 排线 |
| **3** | ⭐ **`'S'` 回轴号**（⭐ `K-132` 复核） | ⭐ **串口** |
| **4** | ⭐⭐ **`span` 卡在哪一步** | ⭐ **串口**（⭐ 追 `'V'`） |
| **5** | ⭐⭐ **ch2 硬件对调实验** | ⭐ 动手拔插 |
| **6** | ⭐ **外置 DAC** | ⭐ 模块接线 |

📌 **串口一旦通了**，⭐ 我能用 `tools/board_probe.py` **自己定时发命令**
（⭐ 包括"标定进行中追 `'V'`"这种人工来不及做的事）⇒ ⭐ **告诉我 COM 口号即可**。

---

## 五、⭐ 一句话

```
⭐ **先烧板、听那一声"叮"** —— ⭐ 听到 = 出声链在真硅片上通了。
⛔ 不需要串口、⛔ 不需要按键、⛔ 不需要任何命令。
🔴 唯一前提：⭐ **`.fs` 是 SRAM 配置 ⇒ 断电后必须重烧**。
```
