hokuu1102/Gowin2026-PolySynth/bringup/13-明日工位上板指南-20260926.md

# 🎯 明日工位上板指南（2026-09-26）

> ⭐ **本文是【照着做】的操作卡** —— ⭐ 每一步都有**判据**，⛔ 不用猜
> **依据**：⭐ 所有引脚/命令都从 `.cst` / 实测读出，⛔ 不凭记忆
> **HEAD**：⭐ `6948e23`（⭐ 2026-09-26 凌晨更新）· ⭐ **回归 63/63** · ⭐ **PnR 0/0 · Fmax 53.285 MHz**

---

## ⚠️ 〇之一、⭐ 2026-09-26 凌晨的变更（⭐ 烧板前先看这段）

| ⭐ 变更 | ⚠️ 对上板的影响 |
|---|---|
| ⭐⭐ **`seq_arb` 接入**（源 A 三级仲裁） | ✅ **行为不变**：无键时手弹源没事件；⭐ 但它**首次接通了曲谱通路** ⇒ ⭐ **灌曲谱会响了** |
| ⭐⭐ **`drum_gen` 接入**（源 B 二选一） | ⚠️ **默认 `SEL_DRUM=0` = 节拍器** ⇒ ⭐ **听感与之前完全一样**<br>🔴 **注意**：`SEL_DRUM=0` 时 ⭐ **鼓机被综合优化掉** ⇒ ⭐ **默认 bitstream 里没有鼓机** |
| ⭐ **Fmax 余量降到 6.6%** | ⚠️ 仍 **0/0 达标**，⭐ 但比上一版（10.9%）紧 |
| ⭐ 6 块待测逻辑 | ✅ **零改动**（⭐ `top.v` diff 逐行核对过） |

📌 **结论**：⭐ **本次 bitstream 与上次【行为等价】**（⭐ 除了曲谱通路新接通）
⇒ ⭐ **昨天的测试步骤全部照旧**，⛔ 不用改。

---

## 〇、⭐⭐ 30 秒总览（⭐ 今天的目标）

```
🔴 **头等任务：把串口弄通**
   ⭐ 因为**后面所有验证都依赖它** —— ⚠️ 没串口就只能靠"听声/看 LED"判断，效率极低
   ⭐ 串口一通 ⇒ ⭐ 我就能用 `tools/board_probe.py` **自己定时发命令**
      （⭐ 包括"标定【进行中】发 `'V'`"这种人工来不及做的事）

⭐ 然后按顺序验 4 件事：
   ① 串口通                    ② 板载还能出声（⭐ 别把已有的搞坏）
   ③ `'S'` 回轴号（K-132）      ④ 外置 DAC 出声（⭐ 新模块）
```

---

## 一、🔴🔴 第一件事：把串口弄通（⭐ 最重要）

### 1.1 ⭐ 先看清「该接哪三根线」（⭐ 从 `.cst` 读出的真值）

| ⭐ FPGA 信号 | ⭐ ball | ⭐ **J9 针号** | ⭐ 接 USB-TTL |
|---|---|---|---|
| ⭐ `uart_rx` | ⭐ **`D14`** | ⭐ **`N26`** | ⭐ **USB-TTL 的 `TX`** |
| ⭐ `uart_tx` | ⭐ **`D15`** | ⭐ **`N25`** | ⭐ **USB-TTL 的 `RX`** |
| ⭐ GND | ⭐ — | ⭐ `J9` 的 **`GND`** | ⭐ **GND** |

### 🔴🔴 **最容易犯的错：接错到 `N24`**

```
⭐ `N24` = `led_oe_n[4]`（⭐ LED 的使能）—— ⛔ **不是 UART！**
⭐ 而 `N25`/`N26` 就紧挨着它 ⇒ 🔴 **非常容易数错一格**
```

⭐ **`J9` 下半部分的针号顺序（⭐ 从 `.cst` 排出来的）**：

```
  N16 ··· N17  N18  N19  N20  N21  N22  N23  N24  N25  N26
            ↑    ↑    ↑    ↑    ↑    ↑    ↑    ↑    ↑    ↑
          led  led  led  oe0  oe1  oe2  oe3  oe4  ⭐uart uart
          _le  _sdi _clk                          _tx  _rx
                                               (D15) (D14)
```

⇒ ⭐ **认准"最边上那两根"** —— `N25`/`N26` 是**靠边**的，⭐ `N24` 是它旁边第一根 LED 线。

### 1.2 ⭐ 操作步骤（⭐ 按顺序）

| # | ⭐ 动作 | ⭐ 判据 |
|---|---|---|
| **1** | ⭐ **确认用的是外接 USB-TTL**（⛔ 不是板载 DAP） | ⭐ 设备管理器里应出现一个新 COM 口 |
| **2** | ⭐ **接线**：`TX→N26`、`RX→N25`、`GND→GND` | ⭐ 三根都要接（⭐ **GND 必须接**，⚠️ 不接会乱码/无响应） |
| **3** | ⭐ **烧板**（⭐ 见 §二） | ⭐ `Operation "Reprogram" Finished` |
| **4** | ⭐ **找 COM 口**（⭐ 命令见下） | ⭐ 记下那个**新出现的**口 |
| **5** | ⭐ **发 `'P'` 试探** | ⭐ **回 `P<通道><4位数>`**（⭐ 8 字节）⇒ ✅ **通了** |

```powershell
# ⭐ 找串口（⭐ 插入 USB-TTL 前后对比，看新增了哪个）
python -c "import serial.tools.list_ports as p; [print(x.device,'|',x.description) for x in p.comports()]"

# ⭐ 试探（⭐ 把 COMx 换成你的口）
python tools\board_probe.py COMx --send "P,P,P"
```

### ⭐⭐ 如果还是不通（⭐ 按这个顺序排查）

| # | ⭐ 检查 | ⭐ 判据 |
|---|---|---|
| **1** | ⭐ **TX/RX 是不是接反了** | ⭐ **对调一下再试**（⭐ 这是最高频原因，⭐ 成本最低） |
| **2** | ⭐ **GND 接了吗** | ⭐ 不接 GND ⇒ **必然不通或乱码** |
| **3** | ⭐ 是不是接在 `N24` 上了 | ⭐ 挪到 `N25`/`N26` |
| **4** | ⭐ 波特率 | ⭐ **`500000`**（⭐ `BAUD_DIV=100`）；⭐ 8N1、⛔ 无流控 |
| **5** | ⭐ USB-TTL 电平 | ⭐ **必须是 3.3 V** ⚠️（5 V 可能损坏 `D14`） |
| **6** | ⭐ 板子烧了吗 | ⭐ `.fs` 是 **SRAM 配置，断电就丢** ⇒ ⭐ 断电过就要**重烧** |
| **7** | ⭐ 串口助手 | ⭐ 关掉"显示发送"（⚠️ 否则分不清收发）；⛔ 别让别的软件占着口 |

📌 **⭐ 通了之后立刻做这件事**：⭐ **把 COM 口号记下来**（⭐ 后面所有命令都要用）。

---

## 二、⭐ 烧板（⭐ 每次上电都要做一次）

```powershell
cd C:\Users\hokuu\Desktop\FPGA\FPGA2026

# ⭐ ① 确认 bitstream 是最新的（⭐ 应存在且是 09-24 23:40 之后）
Get-Item impl\pnr\Gowin2026.fs | Select-Object LastWriteTime

# ⭐ ② 烧（⭐ SRAM 配置）
& "C:\Gowin\Gowin_V1.9.12.03_x64\Programmer\bin\programmer_cli.exe" `
  --device GW5AT-60B `
  --fsFile "C:\Users\hokuu\Desktop\FPGA\FPGA2026\impl\pnr\Gowin2026.fs" `
  --operation_index 1 `
  --cable "USB Debugger A"
```

| ⭐ 判据 | ⭐ 期望 |
|---|---|
| ⭐ 输出 | ⭐ `Operation "Reprogram" for device#1...` + ⭐ **`Finished.`** |
| ⭐ exit code | ⭐ **0** |

### ⚠️⚠️ 两个易错点

```
🔴 `--operation_index 1` 才是【烧写】；⭐ `0` 是"读 ID"（⚠️ 看着也成功，但其实没烧）
🔴 `--fsFile` 必须用【绝对路径】（⭐ 相对路径会报 No such file）
```

📌 **没网/没工具时的备选**：⭐ 用 Gowin IDE 的 Programmer 图形界面（⭐ 选 `Gowin2026.fs` → ⭐ `SRAM Program`）。

---

## 三、⭐ 验证顺序（⭐ 按这个顺序做，⛔ 别跳）

### ✅ 验证 ①：板载还能出声（⭐ 回归基线）

```
⭐ 动作：⭐ 按键 ⇒ 听板载喇叭/耳机有没有声
⭐ 判据：⭐ **有声** ⇒ ✅ 说明烧的是好版本
🔴 若没声 ⇒ ⚠️ **先解决这个**，⛔ 别往下做
```

📌 **背景**：⭐ `PA_EN_n` 的极性在 Console 上是**反的**（⭐ 高 = 出声）——
⭐ 已由 `K-42`/`U-25b` 修过，⭐ 这里只是**确认它没被搞坏**。

### ✅ 验证 ②：`'S'` 是否回轴号（⭐ `K-132` 复核）

```
⭐ 动作：⭐ 发 'S'，⭐ 什么都不按，等 10 秒
⭐ 判据：⭐ 应看到 `s` + 【轴号 0】+ 一串 `!`
         ✅ **每个 `!` 前面都有轴号** ⇒ ⭐ `K-132` 修复生效
         🔴 只有 `s`、没有轴号 ⇒ 🔴 **没修好**
```

📌 **上一轮已上板确认过一次**（⭐ `s0!0!0!0!0!0!0!0!0!` ⇒ 轴号 **9** 次）⇒ ⭐ 这次是**复核**。

### ⭐⭐ 验证 ③：`span` 卡在哪一步（⭐ **串口通了才能做**）

```
⭐ 动作：⭐ 发 'S' 后【立刻】连发 5~10 次 'V'
   ⭐ **用脚本自动做**（⭐ 人工来不及 —— ⭐ `'S'` 几秒就跑完 9 轮）：
   python tools\board_probe.py COMx --send S --follow V --follow-gap 0.05 --follow-count 20
```

| ⭐ 看到 | ⭐ 含义 | ⭐ 下一步 |
|---|---|---|
| ⭐ 一直 `V2xx` | 🔴 卡在 **SETTLE**（⭐ 稳定判定过不去） | ⭐ 印证"ch2 帧间噪声大" |
| ⭐ 一直 `V3xx` | 🔴 卡在 **VOTE**（⭐ 收不齐 8 帧） | ⭐ 查 `sample_valid` 丢帧 |
| ⭐ 在 `1/2/3` 之间跳 | ⭐ 走到 FIRE 被拒 | ⭐ 离散度超 |
| ⭐ `V7xx` | ⭐ 已放弃（rej 到顶） | ⭐ 跑了 9 轮 |

⚠️ **格式**：⭐ `V<state><axis><rej><固定'0'>`（⭐ 末尾那个 `'0'` 是**硬编码常量**，⛔ 不是数据 —— ⭐ `K-133`）

### ⭐⭐ 验证 ④：ch2 的硬件排查（⭐ **本次最重要的硬件实验**）

```
⭐ 动作：⭐ 把"被拒那一路"与"正常那一路"的【传感器对调】
```

| ⭐ 结果 | ⭐ 结论 |
|---|---|
| 🔴 "被拒"**跟着传感器走** | ⭐ **传感器或其接线**有问题 |
| 🔴 "被拒"**跟着通道号走** | ⭐ **板上走线 / ADC 通道**有问题 |

📌 **一次对调就能把范围劈成两半**（⭐ 见 `files/20-代码/待查异常-span被拒-定案-20260925.md`）

⚠️ **⛔ 不要先放宽 `STABLE_TOL`** —— 🔴 那会让 `vmin/vmax` 被噪声撑开
⇒ 🔴 **记下的满行程码是错的** ⇒ ⚠️ **"标定成功但值是错的"比"标定失败"更糟**。

### ⭐⭐ 验证 ⑤：外置 DAC 出声（⭐ 今天的新硬件）

#### 🔴🔴 接线前必读三条（⛔ 违反会烧/没声）

| # | ⭐ 警告 |
|---|---|
| **1** | 🔴🔴 **⛔ 绝对不要接到板载 `J5`** —— ⭐ 它是 **BTL 输出**，⚠️ **接有源音箱会烧** |
| **2** | 🔴 **模块必须【带板载晶振】** —— ⭐ `PCM5102A` 靠它从 BCK 恢复时钟；⛔ 没晶振 ⇒ **没声/爆音** |
| **3** | ⚠️ 接音箱的 **`Line In`**（⛔ 不是功放/BTL 输入） |

#### ⭐ 接法（⭐ 从 `.cst` 读出的真值）

| ⭐ FPGA 信号 | ⭐ ball | ⭐ `PMOD1` 脚 | ⭐ 接 `PCM5102A` |
|---|---|---|---|
| ⭐ `I2S2_BCK` | ⭐ **`F20`** | ⭐ `IO3` | ⭐ **BCK** |
| ⭐ `I2S2_LRCK` | ⭐ **`E22`** | ⭐ `IO4` | ⭐ **LRCK** |
| ⭐ `I2S2_DIN` | ⭐ **`D22`** | ⭐ `IO5` | ⭐ **DIN** |

⭐ **另外必须接**：⭐ 模块的 **`VIN` → 3.3 V**、⭐ **`GND` → GND**。

#### ⭐ 判据

| ⭐ 判据 | ⭐ 期望 |
|---|---|
| ⭐ **音箱出声** | ✅ **且板载【同时】也有声**（⭐ 两路并存） |
| ⭐ 若有示波器 | ⭐ `F20` ≈ **3.125 MHz** · ⭐ `E22` ≈ **48.83 kHz** |
| ⚠️ 若"移位/噪声" | ⭐ 调**外置这一路**的 `JUSTIFY`/`MSB_DELAY`（⭐ 板载那路已验证是对的） |
| ⚠️ 若完全没声 | ⭐ 查：⭐ ① 模块有晶振吗 ② 3.3 V 供电 ③ 接的是 `Line In` 吗 |

📌 **最省事的判别**：⭐ **板载有声、外置没声** ⇒ ⭐ 问题在**外置接线/模块**
（⭐ 因为两路信号在仿真里是**逐拍完全相同**的 —— ⭐ 65536/65536 拍）。

---

## 四、⭐ 命令速查（⭐ 抄下来）

```powershell
cd C:\Users\hokuu\Desktop\FPGA\FPGA2026

# ── 烧板 ──────────────────────────────────────────────
& "C:\Gowin\Gowin_V1.9.12.03_x64\Programmer\bin\programmer_cli.exe" `
  --device GW5AT-60B `
  --fsFile "C:\Users\hokuu\Desktop\FPGA\FPGA2026\impl\pnr\Gowin2026.fs" `
  --operation_index 1 --cable "USB Debugger A"

# ── 串口（⭐ 把 COMx 换成实际口）───────────────────────
python tools\board_probe.py COMx --send "P,P,P"          # ⭐ 试探
python tools\board_probe.py COMx --send S                # ⭐ 发 S
python tools\board_probe.py COMx --send S --follow V --follow-gap 0.05 --follow-count 20
                                                          # ⭐⭐ 抓"标定进行中"的状态
python tools\board_probe.py COMx --listen 3               # ⭐ 纯监听 3 秒
```

### ⭐ 命令字（⭐ 串口里发单个字符）

| ⭐ 命令 | ⭐ 作用 | ⭐ 回什么 |
|---|---|---|
| ⭐ `'P'` | ⭐ 读 ADC 当前读数 | ⭐ `P<通道><4位数>` |
| ⭐ `'V'` | ⭐ 读 `calib_span` 内部状态 | ⭐ `V<state><axis><rej><'0'>` |
| ⭐ `'T'` | ⭐ 重跑 `tare`（零点） | ⭐ `t` … `T` |
| ⭐ `'S'` | ⭐ 逐轴 `span` 标定 | ⭐ `s` + 轴号 + `.`/`!` |
| ⭐ `'X'` | ⭐ 取消标定 | ⭐ `x` |

---

## 五、⚠️ 硬约束（⭐ 今天也适用）

| # | ⭐ |
|---|---|
| **1** | 🔴 **`--operation_index 1`** 才是烧写（⭐ `0` 是读 ID） |
| **2** | 🔴 **`.fs` 是 SRAM 配置，断电就丢** ⇒ ⭐ 断电后**必须重烧** |
| **3** | 🔴 **`N25`/`N26` 是 UART**，⭐ 紧挨 `N24`(LED) ⇒ ⚠️ **数清针号** |
| **4** | 🔴 **⛔ 外置 DAC 绝不接板载 `J5`**（⭐ BTL，**会烧**） |
| **5** | 🔴 **波特率 `500000`**、8N1、⛔ 无流控 |
| **6** | ⚠️ **改任何 RTL 后**：⭐ 先 `iverilog` 秒级编译，⭐ 再跑回归/ PnR |
| **7** | ⚠️ **长时间任务（回归 15 min / PnR 10 min）挂后台**，⛔ 别干等 |

---

## 六、📌 回来之后要告诉我的（⭐ 四项）

```
① ⭐ 串口通了没？⭐ 通的 COM 口号是多少？
② ⭐ 发 'S' 的【完整】回包（⭐ 原样贴）
③ ⭐ 发 'S' 后追 'V' 的结果（⭐ state 是几）
④ ⭐ 外置 DAC 出声了没？⭐ 板载还有声没？
```

⭐ **有了这四项**，我就能判断：
⭐ `span` 卡在**哪一步** ⇒ ⭐ **直接定位根因**（⭐ 不用再猜）。

---

## 七、⭐ 参考文档

| ⭐ 想看什么 | ⭐ 去哪 |
|---|---|
| ⭐ **最新交接** | `交接文档-20260925深夜.md` |
| ⭐ `span` 被拒定案 | `files/20-代码/待查异常-span被拒-定案-20260925.md` |
| ⭐ 外置 DAC 实施记录 | `files/10-硬件/外置DAC通路-实施记录-20260925.md` |
| ⭐ `K-132` 修复详情 | `files/20-代码/待查异常-轴号只回一次-定案-20260925.md` |
| ⭐ 引脚真值 | `constr/top.cst` |
| ⭐ 已知问题清单 | `files/20-代码/已知问题与风险清单.md` |
