hokuu1102/Gowin2026-PolySynth/bringup/02-基石板上板验证方案.md

# 02 · 基石板上板验证方案

> **为什么写这份**：仿真全过、上板却出问题，是本项目**已经真实吃过**的亏
> （`$readmemh` 不上板 `U18`、蜂鸣器悬空一直叫、引脚邻域串扰 `L32/L33`、PLL 全设计无时钟 `L31`…）。
> 手上现在有一块**高云 60K 基石板**，它虽然**没有音频 DAC**，但能补上"**真实硅片**"这一层。
>
> ⚠️ 先记住边界：**基石板 ≠ 最终板**（不同板子、不同引脚网络）——
> 它验的是**数字通路在真硅片上成不成立**，⛔ 不是最终音频音质。

---

## 一、一句话结论

| | 内容 |
|---|---|
| ✅ **基石板能验** | 时钟/复位/下载链路真的通；ROM 初始化**有没有进 bitstream**；真实按键抖动；真实 ADC 采样；整条**数字**合成通路在真硅片上的数值（频率/包络/复音/延迟）；组合毛刺 |
| ⛔ **基石板不能验** | 最终 **PT8211 + NS4263 功放**那段模拟链路、**Dock 的引脚网络**（`V22` 时钟、`Y17/AB17/AA16/AB16` 音频脚、`PA_EN` 上电安全态）、TLC5916 真实器件行为（要灯板） |

---

## 二、能用的"仪器"与引脚（**都有出处，不是猜的**）

| 仪器 | 引脚 | 出处（可信度） |
|---|---|---|
| 系统时钟 50 MHz | `F13` | 官方 60K 基石板例程 `.cst` ×2（`02_LED_test`/`08_UART`）+ ADDA 实测运行 |
| 复位按键 | `D1` | 同上（⚠️ 板载**硬复位键**另有 `J6`、ball 约 `E5`；见上一项目 `FPGA招新题` 仓库里的《ADA107 硬件确认记录》；两种解读都记着） |
| ⭐ **UART**（板载 USB 转串口） | `AB20`(tx) / `T14`(rx) | 官方 `08_UART` + ADDA 实测（500 kbps 传过原始数据） |
| ⭐ **蜂鸣器**（高电平响） | `A13` | 官方 9 个例程一致 + ADDA 实测。⚠️ **必须约束**，否则悬空会一直叫（`PULL_MODE=DOWN`） |
| ⭐ **ADA107 的 10 bit 并行 DAC** | `da_data[0..9]` / `da_clk=C18` | ⭐ **以 ADDA 的映射为准**（在你这块板上实测出过波形） |
| **ADA107 的 10 bit ADC** | `ad_data[0..9]`（⚠️ `[5]` 是**飞线到 `P17`**）/ `ad_clk=AA18` | 同上 |
| **LED / 按键 / 拨码** | `LED0~3` / `BUT0~7` / `SW0~7` | 核心板原理图 Sheet 19（PDF 在本机）——⚠️ **具体 ball 号待抽**（官方 LED 例程给的是 `F21`，可作候选） |

> ### ⚠️⚠️ 一个必须先记住的矛盾：**官方 AD_DA 例程的接线与你这块板不一致**
> | 信号 | 官方 `16_AD_DA_TEST` | ADDA（**实机验证过**） |
> |---|---|---|
> | 位宽 | **8 bit** | **10 bit** |
> | `ad_data[5]` | `V17` | **`P17`（手工飞线）** |
> | `ad_data[3]` | `R19` | `F19` |
> | `da_data[5]` | `T18` | `C20` |
> | 其余多位 | 与 ADDA 不同 | 见 `ADDA/src/top_system.cst` |
>
> **原因**（已查清）：官方例程面向的是**没有龙芯的那版核心板**，而你这块板 `R19` 被 **CPU（LS2K1000）占用**
> ⇒ 官方例程里 `ad_data[3]=R19` 在你这块板上根本不可用（ADDA 的注释明确写了"R19=CPU专用脚(PR2017 不可用)"）。
> ⇒ ⭐ **结论：基石板上的 ADA107 接线一律以 `ADDA/src/top_system.cst` 为准**（那是实际跑通过的）。
> 这又是一次 `C15`（两份"都能工作"的参考互相矛盾 → 用结构判据收敛）。

---

## 三、上板专属坑 × 用哪件仪器抓

| # | 坑（"仿真没问题、上板有问题"的典型） | 抓法 |
|---|---|---|
| 1 | ⭐⭐ **ROM/初始化数据没进 bitstream** ⇒ 全 0、没声音、仿真正常（`U18` 实测过） | UART 回传 **ROM 校验和 + 前 N 点**，PC 与生成文件对比 |
| 2 | 时钟/复位/下载**其实没通**；复位极性反了（一直复位） | 心跳 + UART "我活着" + 蜂鸣器一声 |
| 3 | ⭐ 综合器**静默跳过某文件**（`K-46`）或把调试信号优化掉 | 上板行为对不上 ⇒ 回看构建日志有没有 `Analyzing`/`Compiling` |
| 4 | 引脚/电平/上下拉与实物不符（`D1` 属 1.2V bank；蜂鸣器不约束就一直叫） | 上板现象 + 示波器量脚 |
| 5 | 按键/编码器**真实抖动**（仿真里是理想边沿） | `BUT0~7` 驱动音符，看去抖后是否只触发一次 |
| 6 | 真实 ADC 的采样相位/串扰（上一项目的"偶发坏值"） | DAC→ADC 环回 + UART 抓原始序列 |
| 7 | **组合毛刺**（`OE` 单周期脉冲那类） | 示波器抓 `LE/OE`；仿真侧由 A1 管 |
| 8 | 合成链在真硅片上的数值（DDS 频率/包络/复音） | DAC → 示波器；或环回 → UART → PC 用 `tools/csv_fft.py` |
| 9 | ⭐ **延迟实测**（仿真给 1.233 帧，真值要量 µs） | 事件翻一个 GPIO、首个非零样点翻另一个 ⇒ 示波器量间隔 |
| 10 | 上电首秒行为（未初始化寄存器在真硅片上有确定值，仿真是 X） | 上电观察 + 阶梯 1 的心跳/蜂鸣器 |
| 11 | 真实晶振频率偏差（ppm 级） | UART 计数一段时间 vs PC 时间戳 |

---

## 四、⭐ 上板阶梯（每级都有明确判据，且**下一级才依赖上一级**）

> 📌 原则：**先证明"板子活着"，再证明"我的模块活着"** —— ⛔ 不要一上来就烧整机，那样任何问题都无从定位。

| 阶梯 | 目标 | 判据 | 要写什么 |
|---|---|---|---|
| **0** | 不用板：能综合/时序/引脚 | ✅ **已完成**（`sim/gowin_build.ps1`；Fmax 332.9 MHz、7 脚落位） | — |
| **1** | **板子活着**：时钟/复位/下载/UART | LED 心跳可见（或蜂鸣器每秒一声）+ UART 每 500 ms 打印一行 `ALIVE n` | `board_top_jishi.v`（拟放在本文件夹下的 `jishi` 子目录）的仪器层 + UART 发送（复用 ADDA 的 `uart_tx.v`） |
| **2** | ⭐ **ROM 到底有没有上板** | UART 回传 **校验和 + 前 N 点** == PC 端从源文件算出的值 | 玩具 8 点 ROM（先把通道打通）+ `cmd_parser`（复用 ADDA） |
| **3a** | ⭐ **合成链数字输出看波形**（**旁路 I2S**） | 示波器上看到期望频率的正弦/方波；改音高频率跟着变 | 一行：`da_data = sample[23:14]`（先不经过 `i2s_tx`） |
| **3b** | ⭐⭐ **I2S 发送器也进真硅片** | 把 `i2s_tx` 的 `HP_BCK/HP_WS/HP_DIN` 用 `i2s_to_par` 还原成并行 → 波形与 3a **一致** | `i2s_to_par.v`（逻辑照抄 `tb/models/i2s_rx_model.sv`，已验证过） |
| **3c** | ⭐⭐ **自动验收（不用示波器）**：DAC 用跳线**环回 ADC** | UART 把 ADC 序列回传 → PC `tools/csv_fft.py` 出谱 ⇒ **谱峰频率/SNR 自动判定** | ADC 采样 + `raw_dump`（复用 ADDA） |
| **4** | **真实输入路径**：按键/拨码驱动音符 | 按 `BUT0~7` 出对应音高；连按不重不漏 | 去抖 + `test_mode` 最小版（乙的 `T20`） |
| **5** | **延迟实测** | 事件脚与"首个非零样点"脚间隔 = **实测 µs**（对照仿真的 1.233 帧 = 25.3 µs） | 两个 GPIO 脉冲 |
| **6** | Dock 到手后**换 `.cst` 回归** | 阶梯 1~5 的判据在最终板上重跑一遍 | 换约束（同 die 同封装，逻辑不用改） |

---

## 五、要新写什么 vs 能复用现成资产

| | 内容 |
|---|---|
| ⭐ **可直接复用**（上一项目 **ADDA** 工程，都是自己的代码、且**在你这块板实测跑通过**） | `uart_tx.v` / `uart_rx.v` / `uart_baud_gen.v` / `cmd_parser.v` / `raw_dump.v`（500 kbps 上行帧 + `#DEC` 头，PC 侧上一项目的 `live_scope.py` 直接能吃） |
| ⭐ **可照抄**（本仓库，已在仿真里验证过） | `tb/models/i2s_rx_model.sv` → 抄成 RTL 的 `i2s_to_par.v`（阶梯 3b） |
| **要新写（很少）** | `board_top_jishi.v`（仪器层：拾取内部信号、UART 上报、DAC 输出、心跳）、`jishi.cst`（按 ADDA 映射）、`jishi.sdc`（`F13` 50 MHz）、`Gowin2026_jishi.gprj` + `build_jishi.tcl` —— 都放在本文件夹下拟新建的 `jishi` 子目录里 |
| **PC 侧** | 一条串口收数 → CSV → 直接喂 `tools/csv_fft.py` / `peak_count.py`（**判据复用现成工具**） |

> ⚠️ **为什么要另开一个 Gowin 工程**：Dock 与基石板的**同一个端口名在不同 ball 上**
> （`clk`：Dock `V22` / 基石板 `F13`）⇒ 两个 `.cst` 放进同一工程会 **`IO_LOC` 冲突**，
> 所以基石板必须有自己的 `.gprj`（⛔ 不要去改交付工程）。
>
> ⛔⛔ **目录名必须全 ASCII**：拟建的 `jishi` 子目录 ✅ —— 经验库 `U44` 记着"高云遇到中文路径报 `SORT-1002` 且 Hierarchy 空白"，
> 而**交付仓库路径里已经有中文**（`files` 下的中文目录名），所以**上板工程的路径要单独确认是全 ASCII**。

---

## 六、上板操作的三个纪律（都是踩过的）

1. **下载前 30 秒**：确认 `.fs` 是**这次新生成的**（看时间戳），用
   `programmer_cli.exe --device GW5AT-60B --operation_index 4 --fsFile …\Gowin2026_jishi.fs`；
   ⛔ 别在 Gowin IDE 打开同一工程时同时跑命令行构建（会互相覆盖）。
2. **每次只改一件事**：上板失败时，"改动 + 观测"要一一对应；⛔ 不要一次改三处然后猜。
3. **留活体见证**：任何新工程都要先有一个"不依赖被测模块"的活体信号（心跳/UART）——
   这是 `L31` 那次"全设计无时钟、连 UART 都没输出、综合零 error"换来的教训。

---

## 七、什么时候做

| 时间 | 做什么 |
|---|---|
| **现在（无实物板也能做）** | 阶梯 1/2 的**代码**（仪器层 + UART + 玩具 ROM 通道）**可以先写好并在仿真里验**；等真有板时**当天就能烧** |
| 国庆前（用基石板） | 阶梯 1 → 2 → 3a → 3b → 3c（**把"数字通路 + 上板专属坑"这一层吃干净**） |
| 国庆后（Dock + 手板到手） | 阶梯 4/5/6 + 最终音频（PT8211/功放/手感） |
