hokuu1102/Gowin2026-PolySynth/sim/evidence/p2-37-experiment-20261011/README.md

# `P2-37` 实验：结论 = **白付假设不成立**（2026-10-11 · 已回退）

> ⭐ 审查 `[P2-37]` 自己写着 *"**先做实验判定**奇数 lane 的 test-mode 覆盖 mux 是否白付
> ≈1000 个 LUT4"* ✅ ⇒ ⭐ **本轮把这个实验做了，⭐ 答案是否定的** ✅
> ⭐ 结论**已回退**，⭐ 并把过程写进 RTL 注释（⭐ 防止后人重试 ✅）

---

## 一、⭐ 实验设计（⭐ 判据**在动手之前**就定了）

⭐ 审查自己定的判据原文：

> *"判据：综合报告 LUT 下降 **≥ 500** 且所有 tb 全绿 ⇒ 白付确认，落地"*

⇒ ⭐ 本实验是**预注册**的：⭐ **没达到 ⇒ 不落地** ✅（⭐ 所以回退**不是**"失败了"，
⭐ 而是**判据正常工作** ✅）

### ⭐ 审查的论证（⭐ 我逐条查过源码，⭐ 论证**本身是对的**）

| # | ⭐ 事实 | ⭐ 出处 |
|---|---|---|
| 1 | ⭐ `test_phase_inc_o[...] = (selected && (o == 0)) ? VOICE_INC : 0` ⇒ ⭐ 奇数 lane 的增量是**常量 0** | ⭐ `test_mode_ctrl.v:81-82` ✅ |
| 2 | ⭐ `test_lane_active_o[LANE] = selected && (o == 0)` ⇒ ⭐ 奇数 lane 在 test 档下 `lane_active = 0` | ⭐ `test_mode_ctrl.v:80` ✅ |
| 3 | ⭐ `lane_inc` 的**唯一消费者**是 `phase_q <= phase_q + lane_inc`，⭐ 在 `if (lane_active)` 内 | ⭐ `oscillator_bank.v:725` ✅ |
| 4 | ⭐ `OSC_IDX` 是**编译期常量**（`localparam = g % OSC_PER_VOICE`） | ⭐ `oscillator_bank.v:526` ✅ |
| ⇒ | ⭐ **三条合起来**：⭐ 奇数 lane 在 test 档下"**相位冻结 ⇒ 增量是 don't-care**" ✅ | ⭐ **论证成立** ✅ |

### ⭐ 实施的改动

```verilog
//  只给主 lane 留 test 覆盖（⭐ 奇数 lane 的 mux 应当被折掉 ✅）
wire [PHASE_W-1:0] lane_inc = (test_mode_i && (OSC_IDX == 0))
                 ? test_phase_inc_i[g*PHASE_W +: PHASE_W]
                 : lane_inc_base;
```

⭐ 并按 **铁律④** 同步了 `tb/models/oscillator_bank_ref.v` ✅

---

## 二、🔴 实测结果

| ⭐ 量 | ⭐ 改前 | ⭐ 改后 | ⭐ 判据 |
|---|---|---|---|
| ⭐ **`T_Lut`** | ⭐ **28045** | ⭐ **28045** | 🔴 **没降** |
| ⭐ **`LUT,ALU,ROM16` 里的 LUT** | ⭐ **28039** | ⭐ **28039** | 🔴 **没降** |
| ⭐ **`CLS`** | ⭐ **24359** | ⭐ **24359** | 🔴 **没降** |
| ⭐ `T_Register` / `T_Alu` | ⭐ 17869 / 8327 | ⭐ 17869 / 8327 | 🔴 没降 |

🔴 **一个字节都没变** ⇒ ⭐ **远未达到"≥ 500"** ✅

### ⚠️ 而它**确实改变了行为**

⭐ `tb/w3b/tb_oscillator_bank.sv` 🔴 **红了** ✅
⇒ ⭐ 说明该改动**改变了模块级契约** —— ⭐ 因为那个 tb **直接驱动奇数 lane 的
`test_phase_inc_i` 为非 0** ✅
📌 ⭐ **关键**：⭐ 审查那句"在生产接线下是编译期常量 0"⭐ **只对【顶层接线】成立**，
⚠️ **对【模块级】不成立** ✅ ⇒ ⭐ 这是**第二条"不落地"的理由** ✅

---

## 三、⭐ 为什么没降（⭐ 根因，⭐ 这比结论本身有用）

⭐ 综合器**早就把它折掉了** ✅ ——
⭐ 因为 `lane_active = 0` 时 `phase_q <= phase_q + lane_inc` **整条不执行** ✅
⇒ ⭐ 综合器能证明"**test 档下奇数 lane 的 `lane_inc` 是死逻辑**" ✅
⇒ ⭐ **那个 mux 早就不存在了** ⇒ ⭐ **审查的估算（≈1000 LUT4）是错的** ✅
📌 ⭐ 而审查**恰恰因此写着"先做实验判定"** —— ⭐ **它的方法是对的，⭐ 只是估算错了** ✅

---

## 四、✅ 处置：按判据回退

| ⭐ 项 | ⭐ 状态 |
|---|---|
| ⭐ `rtl/w3b/oscillator_bank.v` | ✅ **回退**（⭐ 并把**否定结果**写进注释 —— ⛔ 防止后人重试 ✅） |
| ⭐ `tb/models/oscillator_bank_ref.v` | ✅ **回退**（⭐ 铁律④：两处必须逐字一致 ✅） |

### ⭐ 回退后的验证（⭐ 三条全绿 ✅）

```text
PASS: oscillator_bank acceptance (T55) - all judgements held
PASS: P5-2 per-voice oscillator_bank is BIT-IDENTICAL to the reference
PASS: tb_top_test_mode_pipe 6229 per-clock comparisons, 0 mismatches
```

⇒ ⭐ 回退**精确恢复**了**已交付状态**（⭐ 即已 push 的 `7a861b4` ✅）
📌 ⭐ 所以**不需要**重跑 PnR：⭐ 资源与位流都与交付一致 ✅
（⭐ 那一次实验性的 PnR 位流 `8034B2DA…` **不作为交付** ✅）

---

## 五、⭐ 下一步（⭐ 本轮的资源基线 + 候选）

⭐ **资源基线（⭐ 已交付）**：

| ⭐ 资源 | ⭐ 用量 | ⭐ 占比 |
|---|---|---|
| ⭐ **`CLS`** | ⭐ 24359/29952 | 🔴 **82%** ⇒ ⭐ **最紧的约束** ✅ |
| ⭐ `Logic` | ⭐ 36893/59904 | ⭐ 62%（⭐ 28039 LUT ＋ 8854 ALU ✅） |
| ⭐ `Register` | ⭐ 17869/60780 | ⭐ 30% ✅ |
| ⭐ `BSRAM` | ⭐ 37/118 | ⭐ 32% ✅ |
| ⭐ `DSP` | ⭐ 25/118 | ⭐ 22% ✅ |
| ⭐ `Actual Fmax` | ⭐ 58.447 MHz | ⭐ 真实余量 **+2.89 ns** ✅ |

⇒ ⭐ **优化目标应当盯 `CLS`（82%）** ✅ —— ⚠️ 而 `P2-37` 说明
"⭐ **看代码猜 LUT 数**"**不可靠** ⇒ ⭐ **每个候选都要先量再落地** ✅

### ⭐ 候选（⭐ 按"预期收益 × 可验证性"排）

| # | ⭐ 项 | ⭐ 预期 | ⚠️ 风险 |
|---|---|---|---|
| 1 | ⭐ `[P2-61]` | ⭐ 关掉 4 块无消费者的 `rom_hard` ⇒ ⭐ **省 4 BSRAM** ＋ ⭐ 一批 32 位宽逻辑 | ⚠️ 低（⭐ 参数开关，⭐ 默认关 ✅） |
| 2 | ⭐ `[P2-24]` | ⭐ 用 `valid` 门控 `calib` 的乘法 | ⚠️ 中 |
| 3 | ⭐ `[P2-35]` | ⭐ `master_mix` 组合穿通 ⇒ 真寄存器（⭐ **时序** ✅） | 🔴 中（⭐ **加 1 拍延迟** ⇒ ⚠️ 会动逐位判据 ✅） |
| 4 | ⭐ `[P3-47]` | ⭐ looper 录制/回放阵列物理复用 | 🔴 高（⭐ 受 `P0-2` 红线约束 ✅） |

📌 ⭐ **建议顺序**：⭐ 先做 `P2-61`（⭐ 低风险、⭐ 收益明确、⭐ 判据就是 BSRAM 计数 ✅），
⭐ 再做 `P2-35`（⭐ 时序，⭐ 但要**先写"延迟 +1 拍不破坏音频"的判据** ✅）。
