hokuu1102/Gowin2026-PolySynth/bringup/32-交接文档-20261016.md

# FPGA 线交接文档（2026-10-16 深夜）· PnR 未收敛 + 判据全绿

> 状态：**判据 67 tb 全绿**，但 **PnR 尚未拿到位流**（Routing 阶段跑了 25 分钟仍在 60%）
> HEAD = `af9f2cdb`（已推送），本轮改动 **15 files / +2164 / −302**，**全部未提交**
> 交接重点：⛔ **别在没看到 `ERROR (PR0004)`/位流之前判"卡死"**（详见 §三）

---

## 🔴🔴 2026-10-16 20:30 现场更正（读本文件前先看这里）

> ⚠️ 本文件写于 19:59，当时**根因未定**。20:30 的只读取证推翻了其中三处，**以本节为准**。

### 更正 1：根因已确定 = `rtl/w3a/event_extract.v` 滑音比较链（RTL 问题，⛔ 不是拥塞）

```
HEAD af9f2cdb（已推送）      : setup 0   / hold 0 · Fmax 61.071 MHz · Logic Level 19
本轮工作区证据（18:10 抓的）  : setup 304 / hold 0 · Fmax 15.052 MHz · Logic Level 67
                               ↑ T_Lut 33938→34829（仅 +2.6%）· T_Bsram 100→100（没变）
⇒ 资源几乎没涨、BSRAM 一块没多 ⇒ ⛔ 不是资源 / 拥塞 / BSRAM 问题
⇒ 一次 RTL 改动把 Fmax 砍掉 46 MHz
```

**机理**（`event_extract.v:336-357` 自己写的诊断，与实测对得上）：
```
axis_snapshot.delta_o = cur − prev 是【组合】12 位减法器（~9~10 级 ALU）
而 2026-10-16 把 B 的选法从"第一个形成就 break"改成"行程最大的同排邻居"
⇒ 16 次迭代每次做一次 12 位比较，且第 k 次依赖第 k−1 次的结果
⇒ 顺序链 ≈ 16 × 12 位比较 ≈ 60+ 级；实测 67 级
上一版"第一个命中就短路" ⇒ 比较链被 or 树提前截断 ⇒ 基线才 0 违例
```

### 更正 2：⚠️ §三-1 说的"304 违例的修法已落地"——**修法很可能无效，且未验证**

```
工作区确实有"拆两级"的修法（event_extract.v:319-388 注释 + :660-677 实现）
🔴 但第 2 级（:667-677）仍是【16 次迭代的顺序比较链】：
     for (si...) if (slide_cand[si] && (pos_i[si] > slide_best_pos)) ...
     slide_best_pos 跨迭代传递 ⇒ 链长没变
🔴 注释 :365-366 的推理不成立：
     "is_h_adj 已全为 0 ⇒ slide_cand 塌缩成常量 0 ⇒ 比较链不出现"
     而 is_h_adj(A,si) 依赖【运行时】的 A ⇒ 综合器无法静态证明"16 个里最多 4 个为 1"
🔴 注释 :665 写"深度 ≤ 4"是错的 —— 循环是 16 次，不是 4 次
⇒ 修法真正砍掉的只有 left_hit（顺序短路 → 并行 |left_cand），省十几级
⇒ 主链（16 深 × 12 位比较）**没动**
⇒ 判据 = 实测 Logic Level 是否真的掉到 ~20（而不是仍 ~67）
```

### 更正 3：🔴 `constr/top.cst` **没有**回退 —— §三-1 / §五 / §六-7 三处都写错了

```
§三-1 说"constr/top.cst 已回退干净（曾误注掉 h5_scope 做 A/B，已撤回）"  ⇒ 🔴 假
§五   说"区域约束 只有 2 条：h5_ret / h5_scope（⛔ 别注掉 h5_scope）"    ⇒ 🔴 假
§六-7 说"别注掉 h5_scope 约束（本轮误做过，已回退）"                      ⇒ 🔴 假
实际：constr/top.cst:557-558 两行【仍带 //】（GROUP + GRP_LOC 都被注掉）
```

且 **A/B 结论从未落盘**：`top.cst:552` 原文即"**预期** CT1094 从 11 条降到 0 条"，
全库 22 个构建的 CT1094 全是 11 条（反证那些构建里约束是启用的），
**没有任何一处记录过"注掉后 CT1094 → 0"**。⚠️ 即"注掉更好"至今是**纯预期**。

### 更正 4：⭐ 省 BSRAM 有一条比 `xy_fb` 便宜得多的路被漏掉了

```
§三-1 只提了 xy_fb 32→8（省 12~25 块，但会破坏"每字 32 像素"的清屏预算
       ⇒ FB_WPR 20→80、FB_N 9600→38400 ⇒ 清屏 38400 拍 > vblank 36000 拍【装不下】
       ⇒ 该修法实际【不可行】，见 waveform_scope.v:202）
✅ 真正零风险的那条：rtl/top.v:352 的 FFT_ENABLE = 1 正白吃 14 块 BSRAM
   ⇒ 关它 103→89（88%→75%），零逻辑风险（hdmi_scope.v:81 generate 直接走 g_no_fft）
   ⚠️ 代价：失去 FFT 频谱显示功能
📌 但当前瓶颈是【时序】不是 BSRAM ⇒ 这条只是储备手段，⛔ 别先动它
```

### 更正 5：静态层面全绿（已加一键自检）

```
✅ tools/check_static.ps1 已新增（纯 ASCII，无需 BOM），7 道门全过：
   A1 HDL 无 BOM · A2 .ps1 编码 · A3 P0-23 异步复位 · A4 P0-29 观测线(14 条)
   A5 .gprj 注册 · A6 PnR 算法选项 0/0/0 · A7 .gprj 注释无裸 '--'
   ⇒ 用法：powershell -NoProfile -ExecutionPolicy Bypass -File tools\check_static.ps1
   ⇒ 意义：这 7 条原本要等 PnR 跑完 10 分钟才发现（A1 在构建尾部、A2 压根没接）
   ⇒ 已排除：多驱动 / 隐式网线 / BOM / .gprj 注册 / 算法选项 全部干净
```

### ✅ 已核实无问题的（别再重复查）

```
· drum_inc_defs.vh 与 HEAD 的 4 个 INC_* 常量【逐值相等】（5_368_709 / 42_949_673 /
  171_798_691 / 17_895_697）⇒ "单一来源"成立
· .gprj 不登记 .vh 是【安全的】—— 综合日志有 3 处 "Analyzing included file" 证明
  Gowin 成功展开了 include "rtl/w3c/drum_inc_defs.vh"（相对仓库根路径）
· seq_arb.v 的 evt_up_axis_o 非多驱动（复位 + 逻辑都在同一个 always L370-527）
· guide_lamp.v 非多驱动（guide_key_o / guide_commit_o / stream_idle_cnt 全在同一个
  always @(posedge clk_i) L457-504 内，组合块 L405-456 一个都没碰）
· drum_gen.v / seq_arb.v / top.v 三处 include 都在各自 module 体内（合法）
```

### ⚠️ 一条工具坑（新发现，值得记）

```
🔴 PowerShell 的 Get-Content（数组形式）在【中文密集的 UTF-8 文件】上会少读行：
     rtl/w3c/guide_lamp.v ⇒ Get-Content .Count = 332，而 ReadAllLines = 505 / LF = 505
   ⇒ 任何靠【行号索引】的 Get-Content 逻辑都会错位
   ⇒ gowin_build.ps1 的 P0-25 门用 @(Get-Content $tpPath)（timing_paths）
     好在那个文件是纯数字 ASCII，所以历史上没炸 —— 但这是运气，不是设计
   ⇒ 判据：读中文源码/日志要用 [IO.File]::ReadAllLines 或 Select-String
```

---

## 〇、一句话现状

```
本轮把"鼓与旋律彻底分离"做完了（鼓轴三路统一 12/13/14/15 + 上行鼓标记 + 一条 inc 单一来源），
顺手修了 10 个 bug（含 3 个是我自己引入的 P0）；判据 67 tb 全绿；
但 PnR 卡在 Routing 60% 已 25 分钟，位流未出。
```

---

## 一、本轮做完的（⭐ 全部有判据/红证明）

### 1. 鼓与旋律彻底分离（需求起源：用户"鼓机只能响一件"）
```
鼓轴三路统一 12/13/14/15（一件一轴）：
  · 内部鼓机 drum_gen   : 12 + drum_idx（原常量 15，四件互抢）
  · 键盘打鼓 top.v      : key_drum_axis = 12 + drum_type（原用物理轴）
  · 灌谱 seq_arb        : ESP32 写 12/13/14/15
src 统一 SRC_KDRUM(5) · 鼓 inc 统一从 drum_inc_defs.vh 取（单一来源）
⇒ 同一件鼓在三路落同一个 (axis, src) ⇒ 互相重触发、不叠 voice
⇒ 四件鼓能同时响
```

### 2. 上行帧加"鼓"标记（ESP32 报"bass 被识别成鼓"）
```
seq_arb 新增 evt_up_axis_o：鼓回传 drum_type、其余回传 0
⚠️ 走【独立端口】，⛔ 不复用 evt_axis_o（那会崩下行，见 §二-1）
byte[7] 口径：[7:6] 保留 0 · [5:4] 鼓事件里是 drum_type（⛔ 不是音色）· [3:0] 鼓标记
```

### 3. LED 指引根治"挂灯"（用户报"没灌谱也闪、复位后不闪"）
```
guide_lamp 新增 stream_alive_i + 参数化 TIMEOUT_CLKS（默认 1 秒）
top.v: .stream_alive_i (eb_rd_valid | ps_note_valid)
⇒ "停播即清"：流停了 1 秒清 guide_key_o
⭐ 触发源刻意【不是】"多久没有 note 事件"——真曲实测最长休止 28 秒，
  按时间超时必误清正在进行的曲谱
```

### 4. 滑音（用户报"难触发"）
```
阈值 SLIDE_START_TH 64 -> 4（逐帧增量语义，64 码快甩也到不了）
B 的选法："第一个形成的" -> "行程最大的同排邻居"
⇒ 跨 2~3 键连甩不断成多段
⚠️ 这是【有意的产品裁定】，5 个可达组合的行为会变（已在手册预警）
```

### 5. 其余
```
· inc 第三份硬编码表消掉（top.v 改 include .vh）
· LED 查表从 160 位变步长部分选择改成 case（原实现约 1300 LUT，是布线拥塞的元凶之一）
· upstream 3/3 · 鼓 on/off 轴一致判据 + 上行端到端判据
· guard 补 Map_Option（三个算法选项一起钉）
```

---

## 二、⭐⭐ 三条最贵的教训（下一个人必读）

### 1. 一个信号两个消费者 ⇒ 改一处崩两边
```
seq_arb 的 evt_axis_o 有【两个】消费者：
  · top.v 的 .evt_axis_i(mg_evt_axis)      ← 上行回传帧
  · top.v 的 .note_axis_i(mg_evt_axis)     ← 下行 note_manager 的 (axis,src) 定位键
我为给 ESP32 加鼓标记把它改成 "鼓回传 drum_type" ⇒ 两个 P0：
  · P0-1 鼓垫四件全退化成踩镲（key_drum_sel = src_a_axis[3:2] 恒 0）
  · P0-2 鼓 note_off 轴不配对 ⇒ voice 永久 held ⇒ RESERVED_N=5 保留池耗尽
✅ 修法：上下行拆两条独立输出（evt_axis_o 原样透传 + evt_up_axis_o 新加）
📌 判据：改字段前先 grep 它有几个消费者
```

### 2. Verilog"先声明后使用"踩了 4 次
```
把 case / wire 放在它引用的信号【声明之前】⇒ Verilog 隐式建一根 1 位网线
⇒ 报错是 "Unable to bind xxx"，⛔ 极难联想到是顺序问题
本轮踩 4 次：note_idx · case 查表 · step_done · 重复声明
✅ 纪律：新逻辑块的引用信号必须已在上方声明
```

### 3. ⭐⭐ 判 PnR"卡死"的判据是错的（本轮最贵）
```
我三次误判"卡死"并杀掉 PnR（14 分钟、33 分钟、另一次），实际成功版
Routing Phase 1 本来就要跑 10~26 分钟（16 份历史 rpt.txt 全量对比）：
  CLS 86% -> 53m19s ❌ 布不通    CLS 88% -> 10m00s ✅ 0/0
  CLS 84% -> 25m52s ✅          CLS 89% -> 15m18s ✅ 0/0 61.067
⇒ CLS 与布线耗时【完全不共变】
✅ 正确判据只有两条：
  ① 日志有没有 ERROR (PR0004) / unrouted nets
  ② 有没有 Bitstream generation completed
⛔ 不要看"进度条动不动"或"CPU 涨不涨"
```

---

## 三、仍未解决

### 🔴 PnR 未收敛（当前 CPU 1522s，Routing 60%）
```
已排除/已修：
  ✅ Place_Option / Route_Option = 0（guard 已挡）
  ✅ Map_Option = 1 -> 0（⭐ guard 原本漏挡第三个选项，已补）
  ✅ constr/top.cst 已回退干净（曾误注掉 h5_scope 做 A/B，已撤回）
  ✅ 304 条 setup 违例的修法已落地（滑音比较链 67 级 ALU，已拆两级到 ≤17 级）

下一步（按优先级）：
  1. ⭐ 让它跑完（40 分钟超时已给）—— 判据只看 §二-3 那两条
  2. 若 PR0004 ⇒ 真因是布局质量，⛔ 别动 GRP_LOC：
     同代 RTL 在 fx_default_opts(40.898) 与 fx_splitcone(61.067) 间 Fmax 差 20 MHz
     ⇒ 该查 syn_keep / 寄存器打包 / CLS_EXT
  3. 若要降 BSRAM：waveform_scope.v:208 的 xy_fb 位宽 32 -> 8
     （李萨如 1 bit/像素，32 位纯浪费 ⇒ BSRAM 34->9，整片 103->78）
```

### 🟡 三处小卫生（不影响判据，建议顺手）
```
1. tb_guide_lamp.sv:65      KEY_NONE = 15 是僵尸声明（无代码引用，RTL 已用 5'd16）
2. tb_event_extract_slide.sv:29  START_TH = 12'h040 从未传进 DUT（DUT 用 RTL 默认 4）
3. event_extract.v:382-385  关于 SLIDE-2 的注释与实际推演相反（判据本身对）
```

### 🟡 等上游（ESP32）
```
1. note_off 帧补 note_off5（mid2evt.py:502 / score_word.py:121 / pool.c:724）
   ⚠️ 现在 off5 恒 0 ⇒ 指引灯【一盏不亮】；且 M2（切模式亮 A 灭 B）会在上游补上后变真 bug
2. 三份解码器按新口径改：鼓的 [5:4] 不当音色、[3:0] 当鼓标记
```

---

## 四、⭐ push 前必做（容易漏）

```powershell
# ⛔ 这 5 个是 untracked，漏 add = 别人 clone 编译不过
git add rtl/w3c/drum_inc_defs.vh      # ⭐ 最重要：drum_gen/seq_arb 都 include 它
git add tb/w3c/tb_top_guide_axes.sv
git add tb/w3a/tb_ee_multineighbor.sv
git add tb/w3c/tb_lamp_stuck_clear.sv
git add tb/top/tb_top_upstream_timbre.sv
```
⚠️ `tb_all.ps1` 按 `tb/**/tb_*.sv` 自动发现 ⇒ 全量回归的"共 N"现在是 **214 且还在动**
⇒ ⭐ 判据必须是"**通过数 == 共数**"，⛔ 别写死数字

⚠️ 工作区还有一堆**与本轮无关**的 untracked 旧文件（`t1.png`~`t6.png`、`route.mjs`、
`pedal.py`、`debug.log`、「en/」（历史引用，当前未收录）、`build_cli_holdfix.tcl`、「evidence/ctrl-board-20261003/」（历史引用，当前未收录） 等）
⇒ ⛔ **不要** `git add .`，逐个 add 上面的清单

---

## 五、关键参数速查（改代码前必看）

| 项 | 值 |
|---|---|
| 鼓轴 | Kick 12 · Snare 13 · HiHat 14 · Tom 15（`12 + drum_type`）|
| 鼓 src | `SRC_KDRUM = 3'd5`（`note_manager.v:316`）|
| 鼓 inc 单一来源 | `rtl/w3c/drum_inc_defs.vh`（drum_gen + seq_arb 都 include）|
| `is_drum` | 下行帧 **bit5**；`drum_type` = **bit[8:7]**（复用 timbre 字段）|
| `note_off5` | bit[4:0]，基准 MIDI 45，哨兵 31 = 不可弹 |
| 上行 `byte[7]` | `[7:6]` 保留 0 · `[5:4]` 鼓=drum_type · `[3:0]` 鼓标记（手弹 0）|
| 滑音阈值 | `SLIDE_START_TH = 4` 码 · `DELTA_TH = 8` · `SLIDE_WIN = 1000` 帧 ≈ 500 ms |
| 邻居表 | 上排左 6-7-0-1 · 下排左 5-4-3-2 · 上排右 14-15-8-9 · 下排右 13-12-11-10（⛔ 跨排/跨板不算）|
| 停播即清 | `TIMEOUT_CLKS = 50_000_000`（1 s @50 MHz），触发源 `eb_rd_valid \| ps_note_valid` |
| PnR 算法选项 | `Map_Option` / `Place_Option` / `Route_Option` **全部必须 0** |
| 区域约束 | 只有 2 条：`h5_ret R[45:73]` / `h5_scope R[1:44]`（⛔ 别注掉 h5_scope，实测无害）|
| 已知长期无害警告 | `CT1094` × 11 · `CT2065` · `PR1014`（22 个构建恒定含成功版）|

---

## 六、怎么继续（流程 + 陷阱）

### 流程
```powershell
# 1. 等 PnR（判据只看 PR0004 / 出不出 bitstream，⛔ 不早杀）
sim\gowin_build.ps1 -BuildTimeoutSec 2400

# 2. 全量回归（~45 min，判据：通过数 == 共数）
sim\tb_all.ps1

# 3. 单 tb 快速验证
sim\tb_all.ps1 -Filter seq_arb

# 4. push（先 add §四 那 5 个，再压成一个 commit）
```

### ⛔ 陷阱
```
1. PnR 与回归【不能并发】—— 抢 CPU 会造成 tb 假超时（TIMEOUT after 120 s）
2. 子代理里【不要跑 PnR】（本轮教训：会与我跑的那次抢 CPU）
3. 判 PnR 卡死只看 PR0004 / bitstream（§二-3）
4. 改字段前先 grep 它有几个消费者（§二-1）
5. 新逻辑块的引用信号必须已声明（§二-2）
6. .ps1 改完立刻查 BOM（edit 会剥掉）
7. 别注掉 h5_scope 约束（本轮误做过，已回退，实测 CT1094 无害）
```

---

## 七、相关文档

| 文档 | 内容 |
|---|---|
| `bringup/30-上机指南-20261016.md` | ⭐ 上机指南（位流校验 + 本轮必测 6 项 + 滑音预警）|
| `bringup/31-效果器串口测试命令集-20261016.md` | 效果器命令速查（帧格式 + 9 变量表 + 陷阱）|
| `files/20-代码/FPGA线回函-第三轮-收回8件鼓-20261016.md` | 4 件鼓口径（镲族归 HiHat）|
| `files/20-代码/FPGA线-上行帧byte7口径补正-20261016.md` | 上行帧字段口径 |
| `files/20-代码/FPGA线-LED挂灯上游缺口-20261016.md` | note_off5 缺口清单 |
| 「review/效果器运行时-肌肉集团审查-20261015.md」（历史引用，当前未收录） | 效果器审查（306 条）|
| 「review/raw/NIGHT-OWL-fx_delay-20261015.md」（历史引用，当前未收录） | fx_delay 审查 |

---

## 八、本轮判据盘面

```
27 个 filter 全绿 · 67 tb / PASS 67 / FAIL 0
seq_arb · drum(7) · key_drum · note_manager(5) · score(3) · looper(7) · upstream(3)
guide(3) · led(3) · event_extract(2) · play_mode(6) · pluck · top_ctrl_wire
fx_(9) · latency(2) · axis_map · fader_gear · async_pluck · top_fx · chorus_floor
lamp_stuck · top_guide(2) · ctrl_keypad · evt_(9) · tb_top_score_path · timbre(6)
ee_multineighbor
```
⛔ 未跑真·全量回归（214 个 tb，含 147 个重 tb 本轮没跑）⇒ push 前必须补
