hokuu1102/Gowin2026-PolySynth/bringup/34-遗留问题与排查计划-20261016.md

# 遗留问题与排查计划（2026-10-16 深夜）

> **当前可上板位流**：`impl/pnr/Gowin2026.fs`
> sha256 `316FE958A45C4A8C2F4D29D285783E742F48E1DEA315953341796B9EB3F7AE80`（22:04:58）
> 代码 `b0cac597`（已推 `origin/main`）· **63 setup / 0 hold** · Fmax 56.482 MHz · CLS 89%
> ⚠️ 工作区**另有 2 处已修但未提交**的改动（见 §一-4/5）⇒ 该位流**不含**它们

---

## 〇、今晚已结清（⛔ 不要再查）

| # | 问题 | 结论 | 证据 |
|---|---|---|---|
| **1** | 🔴 **键盘无声 + 持续杂音** | ✅ **`constr/top.cst` 的 `h5_scope` A/B 从未回退**（10-16 白天注掉）| 恢复后 setup **226 → 63**、Fmax 55.571 → 56.482；**上板键盘恢复** ✅ |
| **2** | 🔴 **失真完全不削顶** | ✅ **USB-TTL 的 TX/RX 接反了** ⇒ 效果器帧根本没进 FPGA | 接对后 `gain 254` 立刻削顶（用户实测）✅ |
| **3** | 🔴 **`drive 64` 不失真** | ✅ **不是 bug** —— 干声 1/8 FS ⇒ 削顶门槛 `gain > 8.0×` | `0.125 × 4.0 = 0.50 FS` ⇒ 不削 ✓ |
| **4** | 鼓机"电子音" | 🟡 **非回归**：`top.v` 的 `VEL_SNARE/HIHAT/TOM`（235/175/220）高于模块默认（200/140/190），**踩镲 +25%**；来源 `465673f8`（2026-10-01）| 用户裁定"暂时这样"|
| **5** | 滑音难触发 | ✅ **已修**（见 §一-4）| `tb_ee_slide_noise` 改前 4 FAIL → 现 8/8 PASS |

---

## 一、遗留问题清单（按优先级）

### P0 —— 卡住上板可用性

#### P0-1 🔴 **失真的可用范围太窄**（`drive` 要 ≥128 才削）

**现象**：`drive 254`（gain 15.875× = **映射上限**）时波形"没有很削顶"。

**已算清的账**：
```
削顶条件：干声 × gain > 1.0 FS
gain 上限 = 15.875×（GAIN_W=16 位 Q4.12，{val_q,8'b0} 装不下更大）
⇒ 干声必须 > 1/15.875 = 【6.3% FS】才削

若 干声 = 1/8 FS (12.5%)  ⇒ 15.875 × 0.125 = 1.98 FS ⇒ 应削得很平
若 干声 = 3% FS           ⇒ 15.875 × 0.03  = 0.48 FS ⇒ 不削 ← 疑似现状
```

**要查什么**：
1. `tdm_render_mixer` → `mx_sample` → `fx_dist.gain_i` 这条链上，**单音/和弦的实际满量程占比**是多少（**算，不是估**）
2. 干声电平在哪一级被压掉的（`norm_gain`？`LANE_W`？TDM 归一化？）
3. 抬哪一级最安全（⛔ 不能踩既有验收 tb 的绝对电平判据 —— 见 `AGENTS.md §五⑨`）

**已知背景**：`bringup/29 §四⑥` 早就记着 *"干声 **1/8 FS（−18 dB）** 的增益结构问题 —— ⭐ 未修（会牵动所有电平判据）"* ✅

**收口判据**：给出"干声实际占 FS 的比例"（可复算）+ "抬哪一级、抬多少、会踩到哪些 tb"。

#### P0-2 🔴 **FX 无任何可观测性**（K-106 违规）

```verilog
top.v:6774   .dist_clip_cnt_o(),      // 🔴 空接 —— 削了多少次，板上看不见
fx_ctrl.py:167   def cmd_list(_args)  // 🔴 参数名 _args ⇒ 只打印出厂值，⛔ 不回读设备
```

⇒ **"帧没进去"和"进去了没效果"在板上无法区分**（今晚为此绕了很久）。

**要查什么**：`clip_cnt_o` / `peak_o` / `en_mask_o` 这些**已算出但无消费者**的信号清单；以及 `uart_tx` 回读通路的最小设计（⭐ `'Z'` 是唯一空闲字母 —— `uart_ui.v:423` 原文）。

**收口判据**：一条串口命令能读回 `mask/gain/trim + 削波计数 + 峰值`。

### P1 —— 真实缺陷，已记档

#### P1-1 🔴 **`RESERVED_N = 5` 鼓池超订**

```
鼓机 4 件（轴 12/13/14/15）· 各占 1 个 voice · 【永不释放】（drum_gen 只发 note_on，EVT_KIND=2'd0）
保留池 = 5（top.v:2727/2803/6216/6646 四处都是 5）
note_manager.v:650  pool_mask = ((cur_src==SRC_AUX)||(cur_src==SRC_KDRUM)) ? (pg>=NORMAL_N) : (pg<NORMAL_N)
⇒ 鼓机与【键盘打鼓】共用这 5 个 ⇒ 鼓机占 4 ⇒ 键盘只剩 1
```

⚠️ **不解释"键盘静音"**（键盘走 `SRC_LIVE` 的 27 路普通池）—— 那是 §〇-1 的约束问题。

**要查什么**：① 4 件是否真的永不释放 ② `top.v:2779` 的账（"节拍器 1 + 鼓机 1 ⇒ 需要 2"）已过期 ③ 最小修法（抬 `RESERVED_N`？给 `drum_gen` 补 note_off？）

#### P1-2 🔴 **剩余 63 条 setup 违例**（HEAD 是 0）

```
最差 25 条路径落点：u_event_extract(12) · u_calib0(8) · u_vibrato_lfo(4)
clk_sys Fmax 56.482 MHz（约束 50 ⇒ 余量 +13%）
CLS 26627/29952 = 89%（接近天花板 ⇒ 布线 15~26 分钟）
```

**要查什么**：逐条读 `impl/pnr/Gowin2026_tr_content.html` 的 25 条最差路径，按**源寄存器 + 扇出**归类，给 top-3 修法。

#### P1-3 ⚠️ **鼓机与灌谱鼓的口径不一致**（用户的原始诉求）

用户原话：*"找一下之前是怎么发声的，改成原来的发声方式，但是逻辑和现在统一"*。
已查清：**发声链一行未改**（`note_manager`/`oscillator_bank`/`perc_env_bank`/`tdm_render_mixer`/`envelope_bank`/`wavetable_bank` 全部未动），4 个 `INC_*` **值逐字相同**；差异只在 **`VEL_*` 覆盖**（§〇-4）与**轴号**。

**要查什么**：鼓机（`SRC_AUX`）与灌谱鼓（`SRC_KDRUM`）在 `note_manager` 里的**全部差异**（力度/分类/扫频/包络），列出可统一的项。

### P2 —— 卫生 / 一致性

| # | 问题 | 位置 |
|---|---|---|
| **P2-1** | `sa_up_axis` 是**死线**（`top.v:6149` 已改用 `up_drum_mark_w`）⇒ `seq_arb.evt_up_axis_o` 与它的复位修复**被综合剪掉** | `top.v:5117/5651` |
| **P2-2** | `top.v:2779` 的账过期（仍写"共用轴号 ⇒ 需要 2"）| `top.v:2779-2780` |
| **P2-3** | `drum_gen` 的 `step_zero_align` 与 `fire` **同拍争写 `pending_q`** ⇒ 小节线那一拍**丢一件鼓**（pre-existing，方向是"丢"不是"多发"）| `drum_gen.v:529-536` vs `:555` |
| **P2-4** | `guide_lamp.stream_timeout` **粘住**（与注释"单拍脉冲"不符；无害）| `guide_lamp.v:478` |
| **P2-5** | 交接文档 `bringup/32` 的 5 处失实（已在 `files/00-总览/赛题对齐-勘误-20261016.md` 更正，⛔ 但正文未改）| `bringup/32` |

---

## 二、排查计划（六路子代理，⭐ 只读）

> ⭐ **全部只读**：只允许 Read / Grep / Glob / `git show` / `git diff` / 只读 PowerShell。
> ⛔ **不许跑构建、仿真、PnR**（会与串行流程抢 CPU，且 `tb_all.ps1` 有 120 s 超时 ⇒ 假红）。
> ⭐ **不许写文件** —— 结论**回报给主代理**，由主代理统一落盘。

| 路 | 任务 | 交付物 |
|---|---|---|
| **A** | **P0-1 干声电平** —— 从 `tdm_render_mixer` 追到 `fx_dist.gain_i`，**算出**单音/和弦的 FS 占比，定位电平在哪一级被压掉，给"抬哪一级 + 会踩哪些 tb" | 可复算的 FS 占比 + 3 个候选修法 |
| **B** | **P0-2 可观测性** —— 枚举"已算出但无消费者"的信号；设计 `'Z'` 回读命令（帧格式 + `uart_tx` 接线 + 需要的寄存器）| 信号清单 + 回读设计 |
| **C** | **P1-1 鼓池** —— 验证 4 件鼓"永不释放"、复算 4+1 的账、给最小修法 | 结论 + 修法 + 判据建议 |
| **D** | **P1-2 时序** —— 逐条读 25 条最差路径，按源寄存器/扇出归类，给 top-3 修法 | 归类表 + 修法 |
| **E** | **P1-3 鼓口径** —— 列出 `SRC_AUX` 与 `SRC_KDRUM` 在 `note_manager` 里的全部差异 | 差异表 + 可统一项 |
| **F** | **P2 卫生** —— 逐条核实 P2-1..P2-5，给出"改/不改"的建议 | 逐条裁定建议 |

## 三、串行流程（⭐ 主代理自己做，⛔ 不与子代理并行）

```
1. 子代理六路回报（只读，可与"写文档"并行）
2. 汇总 → 定修法 → 改 RTL（此时⛔ 无构建在跑）
3. 跑相关判据（sim/tb_all.ps1 -Filter ...）
4. 跑全量回归（~45 min，独占）—— 判据：通过数 == 共数
5. 跑 PnR（~25 min，独占）—— 判据：0 setup / 0 hold ＋ 位流存在
   ⚠️ 重建前【先归档】：tools\archive_bitstream.ps1 -Label <标签>
6. 提交 + push（⚠️ 需用户同意）
```

## 六、2026-10-17 凌晨更新（六路审计全部回报后的**修复队列**）

> ⭐ 六路子代理**全部回报**（A/B/C/E/F/G/H/I/J），主代理已完成 5 项修复并提交。
> ⚠️ **纪律提醒**：`rtl/` 的改动**必须等 PnR 跑完**（PnR 会读工作区文件 ⇒ 边跑边改会污染构建）。

### ✅ 已完成（已提交）

| 提交 | 内容 |
|---|---|
| `ba6f6dc9` | **D3** `drum_gen` `STEPS_C = STEPS[3:0] = 0`（位选静默失效）· **D9** `ctrl_key_map` `LONG_CYC[HW-1:0]` 位选（一旦恰为 2 的幂 ⇒ 长按保护整体失效）· **D8** `evt_upstream` 校验硬写 `8'hA5` 而帧头用 `HDR` · **D7** `seq_arb` 第 2/3 次条件减法不可达（省 ~4 级）· **D6** `tail_3` 死线 |
| `ce8c9660` | ⭐ **calib 夹紧上界寄存器化**（综合 #1，24/25 条，LL 20 ⇒ 省 5~6 级）· ⭐ **滑音 A 判据改用 `key_on`**（上一版 `pos>REL_TH` 在**上板参数下等于没修**，差 24 倍）|

### ⏭ 队列（⭐ 等 PnR 跑完再做，按优先级）

> 🔴🔴 **2026-10-17 06:30 重大更新**：
> · ✅ **位流已出**（`build/bitstreams/20261017-040405-T1-0setup-0hold.fs`，**0 setup / 0 hold**）
> · ✅ **全量回归 216/216 通过**（`sim/evidence/full_regression_20261017.log`）
> · ✅ **已推送**（`origin/main = 9057ac92`，独立 fetch 核对一致）
> · ✅ **Q8 已修**（`top.v` 的 `RESERVED_N` 账订正为"需要 8~9、当前池 5 是超订"）
> · ✅ **LED 重播缺陷已修**（清路改用谱头 tempo 事件；判据 `tb_top_guide_bit6` 场景⑤ 改前必红）
> · ⛔ **旧 CLS 计划大面积作废**（详见 `bringup/36` 的"已被实测推翻的旧计划"一节）

#### ⭐ Q3 的**精确改动清单**（2026-10-17 核实，⭐ 一次做完，⛔ 不许半改）

🔴 **为什么不能半改**：⭐ 只改一部分 ⇒ 多出来的保留 voice 会**走 ADSR**
⇒ **重演 `K-144` 挂音** ✅（`cfg_warn_o` 只判 `<1`，**漏判 `PERC_N`** ⇒ 不会告警 ✅）

| # | 文件:行（⭐ 会随编辑漂移，用下面的**锚点**找）| 改什么 |
|---|---|---|
| 1 | `top.v` `.RESERVED_N (5),`（⭐ metronome 例化处，`wire drm_evt_valid` 附近）| `5` → **8** |
| 2 | `top.v` `.RESERVED_N (5),`（⭐ `drum_gen` 例化处）| `5` → **8** |
| 3 | `top.v` `.RESERVED_N  (5),`（⭐ `u_rec_dump`/另一处例化）| `5` → **8** |
| 4 | `top.v` `localparam integer PERC_N = 5;`（⭐ `RES_PER_BASE` 上方）| `5` → **8** |
| 5 | `top.v` `.RESERVED_N (5),`（⭐ `u_note_manager` 例化处）| `5` → **8** |
| 6 | `rtl/w3b/drum_gen.v:85` `parameter integer RESERVED_N = 5,` | `5` → **8** |
| 7 | `rtl/w3c/metronome.v:50` `parameter integer RESERVED_N = 5,` | `5` → **8** |
| 8 | `tb/e2e/tb_e2e_key_to_sound.sv:63` `localparam integer RESERVED_N = 5;` | `5` → **8** |

⭐ **好消息**：tb 的 `NORMAL_VOICES` 是**派生**的（`:64 localparam integer NORMAL_VOICES = POLY_TARGET - RESERVED_N;`）
⇒ ⭐ **只改 `:63` 那一行**，其余（`:369/:544/:560/:670` 的循环边界）**自动跟着变**（27 → 24）✅

📌 **判据**：⭐ `tb_e2e_key_to_sound`（⭐ 它会打印 `NORMAL_VOICES` 与保留池的检查）
＋ `tb_note_manager_write_share` · `tb_opt08_write_share_reused` · `tb_pool_by_src`
＋ ⭐ 全量回归（判据 = **无 FAIL 且跑满 216 个**）
⚠️ **改完必须跑一次 PnR**（⭐ 变的是 voice 分配 ⇒ 时序/资源会动）

#### ✅ Q3 已完成（2026-10-17 06:52）
8 处全部改成 `8` ✓ · 受影响判据全绿 ✓ · **重跑 PnR 仍 0 setup / 0 hold** ✓
位流归档 `build/bitstreams/20261017-065158-Q3-drum-pool-8.fs`
`sha256 9B46EA6FF19831C8D0F36CBA1A6ED347B586378231B894002D6A876CD84A54AC`
⭐ HOLD worst slack **0.145 → 0.196 ns**（还改善了）

---

#### ⭐ Q2 的**精确改法**（2026-10-17 核实）

🔴 **缺陷**：`drum_cls_r` 只在 **`ST_COMMIT2`** 写一次（`note_manager.v:1623`
`.drum_cls_r[cmt_idx_r*2 +: 2] <= {cmt_kick, cmt_tom};`）
⇒ ⚠️ **同轴 `ST_RETRIG` 重触发时它不更新** ⇒ 分类（Kick/Snare/HiHat/Tom）与
`phase_tr`（已经跟了新八度）**对不上** ⇒ 鼓的音色/扫频档错 ✅
📌 **默认档不可达**（潜在缺陷），但**改八度（T2/T3）后同轴重触发**就成立 ✅

⚠️🔴🔴 **2026-10-17 实测纠错（原计划这 1 行是【错的】，子代理抓到的）**：

原计划写的是 `drum_cls_r[cmt_idx_r*2 +: 2] <= {cmt_kick, cmt_tom};`
⇒ 🔴 **三处错**，照它写会**写错 voice**：

| 错 | 真相 |
|---|---|
| **① 音高不同** ⇒ 分类**必须重算** | `same_hit` 只比 `(axis, src)`、⛔ **不比音高** ⇒ 同轴重触发**可以换音高**（换八度就是干这个的）⇒ ⭐ `cmt_*` 是**上一次提交**的残留 ⇒ 会拿旧音高的分类 |
| **② voice 索引错** | `ST_RETRIG` 成功时复用 `same_idx_r`、⛔ **不是** `cmt_idx_r` |
| **③ `cmt_*` 是陈旧值** | `ST_DECIDE` 只跳 `{ST_IDLE, ST_RETRIG, ST_SCAN}`；`ST_COMMIT` **只从 `ST_SCAN` 进** ⇒ 同轴重触发路径**根本不经过 `ST_COMMIT`** ⇒ `cmt_*` 是"上一次全量提交的残留" |

✅ **实际写法（已 commit `17ccc6ef`，从 `cur_inc` 现算，与同状态的 `phase_r[same_idx_r] <= cur_inc` 同源）**：

```verilog
// ST_RETRIG 里（与 phase_r / vel_r 同一组锁存）
drum_cls_r[same_idx_r*2 +: 2] <= {drum_kick_cur, drum_tom_cur};
// 注意：这里拿的是"本拍现算"，⛔ 不是某个 *_r 寄存器
```

⚠️ 而 `ST_COMMIT2` 那处（新占 voice）则改用**寄存值**（CLS 优化 `a366828b`：
`drum_kick_r` / `drum_tom_r`，在 `ST_COMMIT` 与 `cmt_inc_r` 同拍锁存）⇒
等价性：`cmt_inc_r` 全文件只在 `ST_COMMIT` 写 ⇒ `ST_COMMIT2` 时恒等于那拍的 `cur_inc`；
`base_oct_r` 只在 `base_commit_i` 写 ⇒ 相邻两拍不变 ⇒ **逐位相等** ✓

📌 **先说后做**的教训：计划里"**追加同一句**（与 `:1623` 逐字相同）"这个偷懒写法
在现场被否掉了 —— ⭐ **"同一句"看着最省事，其实掩盖了"两个状态音高不同"这个事实** ✓
⭐ 判据硬证据：`tb_note_manager_write_share` 的运行计数改前/改后**逐个相同**
`commits=561 retriggers=173 collisions=734 drops=8180 all_voice_mask=ffffffff`

#### ⭐ Q7 的**精确改法**（2026-10-17 核实）

🔴 **现状**：`sa_up_axis`（`top.v:5287` 声明 ✓ `:5821` 由 `seq_arb.evt_up_axis_o` 驱动 ✓）
**有驱动、无消费者**（⭐ `:6268-6315` 的注释已说明"不再 OR 上它"✓
⭐ 实际消费者在 `up_drum_mark_w` 那一路 ✓）
⇒ ⚠️ 它是**死线**（⭐ 综合器会删 ✓ 但**注释会误导下一个人** ✅）

✅ **改法（2 处，零功能风险）**：
1. `top.v:5287` 的 `wire [3:0] sa_up_axis;` ＋ `:5821` 的 `.evt_up_axis_o (sa_up_axis),`
   ⇒ 改成 **`.evt_up_axis_o ()`（空接 ✓ 与 `guide_key_o` 同一手法 ✓）** ＋ 删声明
2. `rtl/w3c/seq_arb.v` 的 `evt_up_axis_o`（⭐ 声明 `:151` · 复位 `:401` · 赋值 `:433-435`）
   ⇒ ⚠️ **`seq_arb` 是"冻结模块"** ⇒ ⭐ **先只改 `top.v` 侧空接**（⭐ 零风险 ✓），
   `seq_arb` 内部的死逻辑留着（⭐ 综合器会删 ✓）
⚠️ **过期注释**（⭐ 必须一起改，否则下一个人又被误导）：
`seq_arb.v:390-401` 仍写"X 顺着 `sa_up_axis` 进 `evt_upstream` 的 FIFO" —— **已为假** ✅
＋ `tb/top/tb_top_upstream_timbre.sv` 有 **11 处**引用 `seq_arb.evt_up_axis_o` 当鼓标记出处
（⭐ `:241/:259/:268/:339/:346/:351/:383/:413/:443/:456/:480`）⇒ ⭐ **改注释时要一起核** ✅
📌 **判据**：⭐ `tb_top_upstream_timbre` ＋ `tb_top_score_path`（⭐ 改的是"谁驱动鼓标记"的**可读性**，⛔ 不改行为）

#### ⭐ Q4 的**精确改法**（2026-10-17 核实）

🔴 **缺陷**：`guide_lamp.v:516-524` 的 ON/OFF **直接写位**：
```verilog
if (key_valid) begin guide_key_o[key_sel[3:0]] <= 1'b1; end   // :516-517  note_on
if (key_valid) begin guide_key_o[key_sel[3:0]] <= 1'b0; end   // :523-524  note_off
```
⇒ ⚠️ **无引用计数** ⇒ 按音高指键之后，**同音高还有别的 voice 在响时**，
第一个 `note_off` 一到灯就灭 ✅
📌 **实测比例**（`build/score/*/events.csv`）：OFF 到达时"同音高仍有别的 voice"= **61~77%**
⇒ ⭐ 改成按音高之后这**就是主行为**（⛔ 不是角落）✅

✅ **改法**：加**每键 4~5 位饱和计数**
```verilog
reg [2:0] key_cnt [0:15];                       // ⭐ 饱和到 7
// ON ： if (key_cnt[k] != 3'd7) key_cnt[k] <= key_cnt[k] + 1'b1;
// OFF： if (key_cnt[k] != 3'd0) key_cnt[k] <= key_cnt[k] - 1'b1;
// ⭐ 位图改成派生：guide_key_o[k] 由 (key_cnt[k] != 0) 组合得到
```
⚠️ **代价**：16×3 = **48 FF** ＋ 16 个"!=0"译码（~16 LUT）✅
🔴 **必须同步**：`guide_vis_o = guide_key_o & ~key_active_i`（⭐ `P0-28` 判据钉死 ✓ ⛔ 不许改语义 ✓）
   ⇒ ⭐ 若 `guide_key_o` 从 `reg` 改成**组合派生**，⭐ 要确认 `tb_guide_lamp` / `tb_top_guide_axes` /
   `tb_top_guide_bit6` 里**对 `guide_key_o` 的层次化读取**仍然成立（⭐ 读 wire 也合法 ✓）
📌 **判据**：⭐ 新增"同音高两 voice 叠置、先发第一个 OFF ⇒ 灯**仍亮**；再发第二个才灭"
   （⭐ **当前必红** ✓ 与 `tb_ee_slide_noise` 同一风格：先让它红，再修）✅

#### ⭐ K-106 的**精确改法**（2026-10-17 核实）

🔴 **缺口**：`fx_chain` 有 **7 个可观测输出**（`fx_chain.v:146-156`）：
```
en_mask_o · dly_active_o · chor_active_o · dly_primed_o
· dist_clip_cnt_o[15:0] · trem_lfo_o · pipe_o
```
⭐ 而 `top.v:6894 u_fx (...)` 的接线里**它们大多没被接走** ⇒ ⚠️ 上板时"效果器到底生没生效"
**完全看不见**（⭐ 用户当晚为此绕了 2 小时 ✅）

✅ **改法（两步，⭐ 先做第 1 步就够用）**：
1. **`'Z'` 串口回读**（⭐ `'Z'` 是 A~Y 之外**唯一空闲**的命令字母 ✓
   ⭐ 见 `rtl/w3a/calib_cmd.v:89-231` 的命令表 ✓）
   ```
   'Z' 0 → 回 mask        （1 字节：bit0 dist · bit1 chorus · bit2 delay · bit4 idle）
   'Z' 1 → 回 dist_clip_cnt 高/低字节（2 字节 —— ⭐ 削波计数最有用）
   'Z' 2 → 回 dly_active/chor_active/dly_primed（1 字节打包）
   'Z' 3 → 回 trem_lfo（2 字节）
   'Z' 4 → 回 pipe_o（1 字节 —— 拍数常数，核实用）
   ```
   ⚠️ 复用既有的 `uart_tx`（⭐ `.BAUD_DIV(100)` = 500000 ✓ 见 `top.v:2086` ✓）
   ⭐ 并把 `fx_chain` 的 7 个输出**接进 `top.v`**（⭐ 现在空接 ✓）
2. （可选）把 peak 也加进 `fx_chain`（⭐ 现在没有 peak 输出 ✓ 要新增内部逻辑 ✓）

📌 **为什么值得**：⭐ 这是"**可观测性缺口**"（`K-106`）—— 
⚠️ 效果器调不动的**根因常常是"根本不知道它有没有生效"**（⭐ 当晚 2 小时的教训）✅
📌 **判据**：⭐ `tb_uart_calib_chain`（⭐ 既有 ✓）＋ 新增"发 `'Z' 0` ⇒ 回读到当前 mask"的断言
   ⚠️ **必须非空洞**：⭐ 改 mask 前后回读值**必须不同**（⭐ `C83` 探针假绿的教训）✅

| # | 问题 | 位置 | 为什么该修 |
|---|---|---|---|
| **Q1** | 🔴 **滑音段不受 `enable_i` 门控** | `event_extract.v:749` | `enable_i=0`（标定未完成）期间 `left_ax_r/left_v_r/left_age` **保留脏值**，`slide_valid_o` 仍可能抬 ⇒ 下游 `slide_active_i` 抑制 `note_off` ⇒ **与 T38 挂音同族**。修法：`:749` 加 `enable_i !== 1'b0`，并在关断时清 `left_v_r` |
| **Q2** | 🔴 **`drum_cls_r` 在 `ST_RETRIG` 不更新** | `note_manager.v:1496-1530` vs `:1623` | 改过 `base_oct_r` 后同轴重触发 ⇒ **分类是旧值而 `phase_tr` 已跟新八度** ⇒ 分类与实际扫频档对不上。默认档不可达，潜在缺陷 |
| **Q3** | 🔴 **`RESERVED_N = 5` 鼓池超订** | `top.v` **5 处**（`:2765/:2841/:6254/:6684` + `PERC_N@:6562`）+ tb 2 处 + 模块默认 2 处 | 需求 **8**（鼓机 4 永不释放 + 键盘/灌谱鼓 4），池 5 ⇒ 缺 3。⚠️ **静默半改**：`cfg_warn_o` 只判 `<1` ⇒ 漏 `PERC_N` ⇒ 多出的保留 voice 走 ADSR = **重演 K-144 挂音** |
| **Q4** | 🔴 **LED 无引用计数** | `guide_lamp.v:493-499` | 按音高指键后，**OFF 到达时同音高还有别的 voice 在响 = 61~77%**（实测）⇒ 灯被**提前熄灭**。修法：每键 4~5 位饱和计数（16×5=80 FF），只在 `cnt==0` 时清位 |
| **Q5** | 🟠 `guide_lamp` 卫生 | `:364/:476-483`（`stream_timeout` 粘住）· `:157/358/363/365`（`TIMEOUT_CLKS≤1` 无自检）· 文件头缺 `default_nettype none` · `:219 AXIS_SH` 死代码 · 注释"27 FF"实为 26 | 一小时内的活，一起做 |
| **Q6** | 🟠 `drum_gen` 的 `fire` 同拍覆盖 | `drum_gen.v:460`（**1 行**）| `fire = has_pending & transport_i & ~step_zero_align & ~pos_rst` ⇒ 否则 `pos_rst` 落在装载后 ≤3 拍时**多发残余**（推翻 `top.v:2873-2879` 的承诺）。当前参数近乎不可达 |
| **Q7** | 🟠 `sa_up_axis` 死线 + 过期注释 | `top.v:5173/:5707` + `seq_arb.v:151/:401/:433-435` + 11 处 tb 注释 | 零可观测效果；`:374-384` 的注释（X 传播进 FIFO）**已为假** |
| **Q8** | ⚠️ `top.v:2817` 的账过期 | `top.v:2817-2818` | 仍写"节拍器 1 + 鼓机 1（共用轴号）⇒ 需要 2"；**实际是四轴**。连带 `:5922-5924`（"最多 5 音"应 8）|
| **Q9** | ⚠️ `mid2evt.py` 排序与注释相反 | `tools/mid2evt.py:450-460` | 同 tick **ON 排在 OFF 前** ⇒ 重击音被立即关掉 + LED 灯只亮 20 ns。**一行修**（⭐ 但属 ESP32/工具侧，已写进给 ESP32 的需求文档）|

### ⛔ 已确认**不是**问题（避免重复排查）

| 项 | 结论 |
|---|---|
| 四个改动模块的多驱动 | ✅ 全干净（含历史上炸过的 `evt_upstream` / `ctrl_key_map`）|
| `guide_lamp` 多驱动 / 复位 / 位宽 / 哨兵 / 表项 | ✅ 全对（表与 `axis_map` 逐项一致、`KEY_NONE` 正确、实测 26 位计数器）|
| `drum_gen` `:534` vs `:555` 同拍覆盖 | ⚠️ **结构上存在但已定量证明当前不可达**（`pending_q` ≤4 拍排空，而 step 周期 ≥49 万拍）|
| `note_manager.v:1969` 两条鼓路 | ✅ **同一行** ⇒ 都走 `rom_noise` 噪声表 |
| `top.v` 两处 `DRUM_KICK_MAX/TOM_MAX` | ✅ **同值**（10M/20M，靠顶层显式传，⛔ 不靠默认值）|
| `stream_timeout` 粘住 | ✅ **无害**（清 0 是空操作，且 `:482` 在 `:485` 之前 ⇒ 流恢复首拍的 ON 能活）|

### ⚠️ 行号漂移（⭐ 引用请用符号名，别用行号）

`bringup/34` 早期写的行号**已全部漂移**（`top.v` 改了 19 行 ⇒ 之后整体 +18）：
`RESERVED_N` `2727/2803/6216/6646` → 实际 **`2765/2841/6254/6684`** ＋ `PERC_N@6562` ·
`sa_up_axis` `5117/5651` → **`5173/5707`** · `drum_gen` `529-536/555` → **`541-548/561-572`**

### 📌 一条"与 ESP32 有关、但可能更大"的待核项

```
tools/mid2evt.py:115           FS = 50_000_000
rtl/w3a/axis_map.v:280,324,353 fs = 50MHz/1024 = 48828.125      ← 差 2^10
⇒ 键盘路与曲谱路的 phase_inc 口径是否真等价？可能是静默的音高偏差
```

| # | 纪律 | 今晚的代价 |
|---|---|---|
| 1 | 🔴 **重建前先归档 `impl/pnr/Gowin2026.fs`** | 我删掉了一版还在用的位流（`gowin_build.ps1` 每次启动清 `impl/pnr`，而 `impl/` 是 git-ignored）|
| 2 | 🔴 **PnR 与回归⛔ 不并发** | 会抢 CPU ⇒ `TIMEOUT after 120 s` **假红** |
| 3 | 🔴 **`edit` 会剥掉 `.ps1` 的 BOM** ⇒ 改完立刻 `check_ps1_encoding.ps1` | 项目里踩过两次 |
| 4 | 🔴 **验证方法本身也会说谎** | 我用 PowerShell `>` 算 blob 哈希（会加 BOM）⇒ 差点误报"push 的不是这版" |
| 5 | ⭐ **契约只认 tb** | 我给 `evt_guide_seen_r` 多加一个清点 ⇒ `tb_top_guide_bit6` 立刻红（26/28）；去掉后 28/28 |
| 6 | ⭐ **`Get-Content`（数组形式）在 CJK 密集的 UTF-8 上会少读行** | 用 `[IO.File]::ReadAllLines` |

#### 🔴 Q4 实测结论（2026-10-17 11:00）—— **代码 + tb 期望必须【一起改】**

⭐ 我按上面的改法给 `guide_lamp.v` 加了每键 3 位饱和计数（27 行）⇒ **既有判据立刻红了**：
```
guide      通过 0 / 共 3   （tb_guide_lamp / tb_top_guide_axes / tb_top_guide_bit6 全红）
top_guide  通过 0 / 共 2
```
🔴 **真因（不是我的 bug，是【契约变了】）**：
   老 tb 断言「**一个 note_off 就熄灯**」；
   而 Q4 的语义是「**最后一个 note_off 才熄灯**」
   ⇒ ⭐ 三个 tb 里凡是「发一个 ON 再发一个 OFF ⇒ 断言灯灭」的用例，**都要改成**
     「发 N 个 ON ⇒ 发 N−1 个 OFF 仍亮 ⇒ 发第 N 个 OFF 才灭」

⚠️ **踩到的坑（记档）**：我的锚点 `guide_commit_o <= 1'b0;` 在文件里**出现两次**
   （复位块 + else 的默认清零）⇒ `String.Replace` **两处都插了**
   ⇒ 🔴 第二处变成「**每拍清零计数**」⇒ 计数完全失效
   ⇒ ⭐ **教训：Replace 前必须确认锚点【唯一】**（Select-String | Measure-Object 数一下）

✅ **当前处置**：已**回退 Q4**（guide_lamp.v 回到 
4bacddb），判据恢复 3/3 + 2/2 ✅
📌 **下一轮做法**：⭐ **一次改完代码 + 三个 tb 的期望**，再跑；⛔ 不要只改代码

#### Q4 真因已定位（2026-10-17 14:00）-- 不是 bug，是计数器跨场景累积

`tb_guide_lamp.sv:200-216` 的 `send_ev` 是【单拍脉冲】（`note_valid` 只高 1 拍）
=> 一个 ON + 一个 OFF 本该正常（计数 1->0 熄灯 OK）
RED 但三个 tb 的【前面场景】已经给【同一个音高】发过多次 ON => 计数累积到 2+
    => 后面只发一个 OFF => 只减到 1 => 灯仍亮 => 断言"灯灭"必红

下一轮的做法（三选一）：
1. 场景开头清计数器 -- `key_cnt` 在模块内，tb 没法直接清；靠 `stream_timeout` 触发不了（tb <1s）=> 不可行
2. 【最简单】每个场景用【不同的音高】=> 计数器天然隔离
3. 在 tb 里 `force dut.key_cnt[...] = 0`（层次化）-- 可行但要 release

判据要求不变：新增"同音高两 voice => 先发一个 OFF 仍亮、再发一个才灭"（改前必红）
