hokuu1102/Gowin2026-PolySynth/bringup/35-排查结论-20261016-夜.md

# 排查结论（2026-10-16 深夜 · A/B/C/E 已完成，D/F 待补）

> 承接 `bringup/34-遗留问题与排查计划-20261016.md`
> 六路子代理里 **5 路挂了**（启动后立刻死）⇒ A/B/C/E **由主代理自己完成**；C 一路跑通并**纠正了主代理两处错误**
> 本文件只写**结论**，原始推导见各节引用的 `文件:行号`

---

## A ✅ 失真"没削顶"的真因 = **屏幕上看不清**，⛔ 不是失真坏了

### A-1 关键数字（`rtl/w3b/tdm_render_mixer.v:582`，含可复算推导）

```
⭐ 单音峰 = 24.9% FS = −12.1 dBFS
   推导：单 voice 满幅两 lane 同相 ⇒ sh24 = 8 354 816 ≈ 99.6% FS
        ⇒ sh_norm = sh24 × 64 >>> 8 = 2 088 704 ⇒ 24.9% FS
```

⚠️ **更正一个流传的口径**：`bringup/29 §四⑥` 记的"干声 **1/8 FS**"**偏小** —— 代码真值是 **24.9% FS**。
（`:591` 自己写着"文档承诺 69% FS ⇒ 差 8.8 dB"，两因子：归一化基准 88→64（−2.8 dB）＋ `OUTPUT_HEADROOM_SH=1`（−6.02 dB））

### A-2 `drive` 各档的完整账（干声 24.9% FS）

| `drive` | gain | **clipper 输入** | 削? | **出口幅度（屏幕占比）** |
|---|---|---|---|---|
| 64 | 4.000× | 1.00 FS | 不削 | 24.9% |
| 128 | 8.000× | 1.99 FS | 🔴 **削平** | 12.5% |
| 160 | 10.000× | 2.49 FS | 🔴 削平 | 10.2% |
| 200 | 12.500× | 3.11 FS | 🔴 削平 | 7.8% |
| **254** | 15.875× | **3.95 FS** | 🔴 **削平** | **6.3%** ← 用户说"没很削顶"的这一档 |

### A-3 🔴 结论：**"归一化"本身让平顶看不见**

`drive` 的设计是"推力↑而**音量不变**" ⇒ `trim = 2048/gain` ⇒ **gain 越大，出口越小**。
⇒ `drive 254` 的波形只剩 **6.3% 屏幕** ⇒ 平顶**看不出来** ✓
⇒ 用户之前发 `gain 254` + `trim 254` 时"**炸了**" —— 那正是**削得最狠**（出口饱和 100% FS）✓
⇒ **失真一直是好的** ✓

### A-4 想看平顶（不靠猜）

```
71 11 FE FF FF FF     gain = 254  ⇒ 15.875×
71 12 80 FF FF FF     trim = 128  ⇒ 1.0× ⇒ 出口【饱和到 100% FS】= 满屏方波
```
⭐ 代价：满量程输出 = 很响，**物理上躲不掉**（满幅就是满幅）

### A-5 真正值得修的（P0-1）

若把干声从 24.9% 抬到 69% FS ⇒ **`drive 32~64` 就能削**，可用范围宽 **4 倍** ✓
⚠️ 但 `tdm_render_mixer.v:755-756` 记着"失谐让两 lane **周期性 100% 同相** ⇒ 相干 ×2 ⇒ 138% 满幅"
⇒ 抬响度**可能复发"音色不同的音"**（`AGENTS.md §五⑨` 记的已回退路线）
⇒ **这是用户决策，⛔ 不擅自改**

---

## B ✅ 可观测性缺口（K-106 违规）—— 已核实，方案可行

### B-1 `fx_chain` 的 **7 个输出全空接**（`rtl/top.v:6773-6774`）

```verilog
.en_mask_o(), .dly_active_o(), .chor_active_o(), .dly_primed_o(),
.dist_clip_cnt_o(), .trem_lfo_o(), .pipe_o()      ← 🔴 削波计数就在这
```

### B-2 两个"疑似 bug"的核实结果

| 疑点 | 结论 |
|---|---|
| `uart_tx` 注释说 `BAUD_DIV=50`（1 Mbps）而接收侧是 100 | ✅ **不是 bug** —— `top.v:2086` 实际传 `.BAUD_DIV(100)` ✓ 500 kbaud 一致 |
| `uart_ui.v:423` 说"只剩 `'Z'` 空闲" | ✅ **属实** —— grep `rtl/w3a/calib_cmd.v:89-231` 得 A–Y **25 个全用**，`'Z'` 是唯一空闲 ✓ |

### B-3 `'Z'` 回读设计（待实现）

```
命令：0x5A（'Z'）
回包：mask / gain / trim / 削波计数(16 位饱和) / 峰值
接线：fx_chain.dist_clip_cnt_o → top.v 新增寄存器 → calib_cmd → uart_tx
      ⭐ 全程 evt_merge 下游 ⇒ ⛔ 不会成组合环
寄存器：削波计数已在 fx_dist 里（`:110`），只需引出 + 打包
风险：要读既有 tb_uart_ui / tb_calib_cmd 的断言，确认新增字母不撞
```

---

## C ✅ `RESERVED_N` 鼓池超订 —— **本项纠正了主代理两处错误**

### C-0 ⚠️ 更正 ①：`top.v` 的行号**全错**（漂移）

| 主代理给的（错） | 实际（对） | 对象 |
|---|---|---|
| `:2727` | **`:2765`** | `.RESERVED_N(5)` → `u_metronome`（仅自检） |
| `:2803` | **`:2841`** | `.RESERVED_N(5)` → `u_drum_gen`（仅自检） |
| `:6216` | **`:6254`** | `.RESERVED_N(5)` → **`u_note_manager`** ★ 唯一真正生效 |
| `:6646` | **`:6684`** | `.RESERVED_N(5)` → **`u_tdm_render_mixer`** ★ 必须与 `:6254` 相等 |
| （漏了） | **`:6562`** | `localparam integer PERC_N = 5;` ★ **第 5 处** |

⇒ **是 5 处，不是 4 处** ✓

### C-1 ⚠️ 更正 ②：主代理说的"鼓 voice 会随包络释放"**是错的**

```verilog
note_manager.v:564   live_mask = gate_r | hold_mask | env_active_r | sus_hold_r
note_manager.v:1417  gate_r[i] <= 1'b0;     ← 唯一能【长期】清 gate 的地方 = note_off 分支
drum_gen.v:96/486    EVT_KIND = 2'd0 ⇒ 鼓机【恒发 note_on】
```
⇒ **`gate_r` 恒 1 ⇒ `live_mask` 恒 1 ⇒ `free_mask` 恒 0 ⇒ 那 4 个 voice 永久 held** ✓
（主代理只看 `env_active_r`，漏了 `gate_r` 也在 `live_mask` 里 —— **C 是对的**）

### C-2 真实账：**需求 8，池 5**

| 需求方 | src | 轴 | 占几个 | 会释放吗 |
|---|---|---|---|---|
| `drum_gen`（**交付默认 `SEL_DRUM=1`**）| 3 | 12/13/14/15 | **4**（pattern 1/2/3）/ 3（pattern 0） | ❌ **永不** |
| `metronome`（`SEL_DRUM=0`）| 3 | 14 | 1 | ❌ 永不 |
| 键盘鼓垫 / 灌谱鼓 | 5 | 12+`dtype` / 帧给的轴 | ≤4 | ✅ 有 off 配对 |
| **合计（交付默认档）** | | | **8** | 池只有 **5** |

⇒ 🔴 `RESERVED_N=5` 是按"**节拍器 1 + 鼓机 1**"（`top.v:2817`）算的，
而 `drum_gen.v:554`（10-16 统一鼓轴）把鼓机从 **1 个 voice 变 4 个** ⇒ **前提被推翻** ✓

⚠️ 过载时**不是"丢事件"而是"互相抢占 churn"**（`ST_COMMIT2 :1617-1619` 改写被抢 voice 的 `axis_r/src_r`）
⚠️ `age_r` 饱和后（~1.34 s）抢占退化成"**永远抢最低索引 voice 27**"（`:1196-1199`/`:1005-1018`）
⚠️ 真正丢事件那条路（`:1566` `best_valid=0`）**窄窗口可达且完全无观测**（`lost_cnt_r` 只统计 FIFO 满）

### C-3 修法

| # | 改什么 | 处数 | 风险 |
|---|---|---|---|
| **A** | `RESERVED_N` 5→**8**（建议 **10**，否则余量为 0）| **top.v 5 处** + tb **2 处** + 模块默认 2 处 | 🔴 **静默半改**：`cfg_warn_o` 只判 `<1` ⇒ **配不上也照样绿**；漏 `PERC_N` ⇒ 多出的保留 voice 走 ADSR = **重演 K-144 挂音** |
| **B** | 给 `drum_gen` 补 `note_off` 配对 | `drum_gen.v` 1 模块 | 改了**已交付模块契约**；off 早于包络尾 ⇒ **鼓声被切** |
| **C2** | 由 `top.v` 在源 B 关闭时补发 `note_off`（只动 top.v）| 1 处 | 要造合成事件源 + 保证 on 先 off 后 |
| ~~C3~~ | 鼓机退回单轴 | 1 行 | 🔴 **回归**到"四件同拍只响一件"⇒ **不建议** |

**推荐：A（取 10）+ B 或 C2**

---

## E ✅ 三条鼓路的力度表 —— **"电子音"的真因**

### E-1 三条路的力度来源

| 路 | 来源 | 底鼓 | **军鼓** | **踩镲** | 嗵鼓 |
|---|---|---|---|---|---|
| **内部鼓机**（`drum_gen`, src 3）| **固定值**（`top.v:2855-2857` 覆盖）| 230 | 🔴 **235** | 🔴 **175** | 220 |
| **键盘打鼓**（src 5）| `max(键盘力度, 下限)`（`top.v:5864-5867`）| 230 | 210 | 175 | 200 |
| **灌谱鼓**（src 5）| **帧里的 `vel`**（无下限）| 由谱面决定（通常更低）| ← | ← | ← |
| （模块默认，未覆盖时）| | 230 | 200 | **140** | 190 |

### E-2 结论

```
⭐ 军鼓：鼓机 235 ＞ 键盘 210 ＞ 灌谱（谱面）
⭐ 踩镲：鼓机 175 ＝ 键盘 175（下限），但比【模块默认 140】高 +25%
⇒ 🔴 两条【高频】鼓在鼓机路上【最响】 ⇒ 噪声更突出 ⇒ 听感"电子"
⇒ ✅ 完全对上用户的两条描述："主要是频率比较高的那两个" + "灌谱时没这么电子"
```

📌 **`top.v:6594` 自己写着**：*"Kick `VEL_KICK=230` ⇒ 峰值 58880 = **满幅 90%**"* ⇒ 力度已接近上限
📌 覆盖来自 `465673f8`（2026-10-01，"键盘打鼓模式 + 鼓音高拉开 + …"）⇒ **⛔ 不是本轮回归** ✓

### E-3 统一方案（对应用户原话"改成原来的发声方式，但逻辑和现在统一"）

⭐ **让三条路共用同一张"每件鼓基础力度"表** —— 即把 `drum_gen` 的固定 `VEL_*` 与
`key_drum_base_vel`（键盘下限）**合并成一张表**，灌谱鼓保持"帧力度但受同一下限约束" ✓
⇒ 一件鼓在三路力度一致 ⇒ 音色一致 ✓

### E-4 顺带核实（✅ 一致，无需改）

```
top.v:6237-6238   note_manager      .DRUM_KICK_MAX(10_000_000) .DRUM_TOM_MAX(20_000_000)
top.v:6459        oscillator_bank   .DRUM_TOM_MAX(20_000_000)
⇒ 两处分类阈值【同值】✓（否则"分类与实际扫频档对不上"）
```

---

## D ⏳ 剩余 63 条 setup 违例 —— **待新构建**

⚠️ **`impl/pnr/` 被正在跑的构建清空了** ⇒ 旧的 `Gowin2026_tr_content.html` **没了**
（这正是"重建前先归档"该覆盖的东西 —— `tools/archive_bitstream.ps1` 只归档 `.fs`，⛔ 不含 `tr_content.html`）

**已知（构建前的快照）**：
```
最差 25 条路径落点：u_event_extract(12) · u_calib0(8) · u_vibrato_lfo(4)
clk_sys Fmax 56.482 MHz（约束 50）· CLS 89%
```
⇒ 新构建出来后再逐条读，按"源寄存器 + 扇出"归类

---

## F ⏳ P2 卫生五条 —— 待补

`sa_up_axis` 死线 · `top.v:2817` 过期账 · `drum_gen` 的 `step_zero_align` 争写 ·
`guide_lamp.stream_timeout` 粘住 · `bringup/32` 的 5 处失实

---

## 优先级建议（给用户裁定）

| # | 事 | 价值 | 代价 |
|---|---|---|---|
| **1** | **B-3 加 `'Z'` 回读**（削波计数 + mask/gain/trim）| ⭐⭐⭐ 今晚为此绕了 2 小时；以后一次定位 | 1 次 PnR |
| **2** | **E-3 统一三条鼓路的力度** | ⭐⭐⭐ 直接解决用户听感问题 | 改 top.v 1 处 + 1 次 PnR |
| **3** | **C-3 修鼓池**（`RESERVED_N`→10 + note_off）| ⭐⭐ 真实缺陷，情境性 | 改 5+2+2 处 + 新判据 |
| **4** | **A-5 抬干声电平** | ⭐⭐ 失真可用范围宽 4 倍 | ⚠️ 可能复发"音色不同的音"⇒ **用户决策** |
| **5** | D 剩余时序违例 | ⭐ 63 条，物理上仍满足 50 MHz | 待数据 |
| **6** | F 卫生 | ⭐ 可读性 | 低 |
