hokuu1102/Gowin2026-PolySynth/bringup/27-交接-FX运行时控制-20261015.md

# 交接：效果器运行时控制（2026-10-15）

> **交接对象**：队友（继续跑 PnR / 上板验收）+ 未来的自己
> **基线**：`origin/main` = `4a669c7c`，本轮在其上叠加
> **本轮提交**：`78a56618`（fx 运行时）· `eadab080`（工具 + 复盘）
> **关联文档**：`review/fx-version-review-20261015.md`（队友的审查）
> · `files/20-代码/效果器复盘-20261015.md`（我的复盘）

---

## 一、当前状态（先看这个）

| 项 | 状态 |
|---|---|
| 效果器模块 | 已挂载进 `top.v`，`.gprj` 已登记 4 个文件 |
| 效果器参数 | **运行时可改**（本轮改的，原来只能编译期定） |
| 串口控制 | **可用**，走串口屏的帧协议（见第三节） |
| 综合 | 通过，**0 ERROR**（⚠️ 但 WARN 不能一笔带过 —— ⭐ 见 `sim/evidence/gowin_build.log` 与 `sim/evidence/gowin_m0_timing.txt`） |
| PnR | ⭐ **已完成**（`sim/evidence/gowin_build.log` 末尾 = `Bitstream generation completed` @ **21:07:39**；`gowin_m0_timing.txt` = **0 setup / 0 hold**）。⚠️ **但该位流早于本轮改动** —— `rtl/w3c/uart_ui.v` 的 mtime 是 **22:31**（⭐ 含 ×256 映射与 `body_q` 扩位）⇒ 🔴 **该位流⛔ 不含 ×256**，上板前需重跑 PnR ✅ |
| 全量回归 | **本轮还没跑**（PnR 跑完才能跑，两者不能并行） |
| 推送 | 未推（本地领先 `origin/main` 3 个提交） |

### PnR 的历史规律（重要）

```
run A（带旧 .pr）  到 Routing Phase 0 = 1927 s，之后静默  7.9 min 被杀
run B（带旧 .pr）  到 Routing Phase 0 =    ?  ，之后静默 27+  min 被杀
run C（清 .pr）    到 Routing Phase 0 =  840 s，之后静默 65   min 被杀
本轮（清 .pr）     到 Routing Phase 0 =  647 s（最快），之后静默 18.5 min 起
```

**结论**：清 `impl/pnr` 能让**前期阶段快 2~3 倍**，但**布线阶段本身仍然慢**。
根因是设计规模（CLS 占用高），不是配置问题 —— 已核实 `.gprj` 与 `constr/`
与队友那次成功的构建**完全一致**（76 vs 76 文件、零差异）。

**给继续跑的人**：
- `sim/gowin_build.ps1` 已默认清 `impl/pnr`（有 `-KeepPnr` 逃生口）
- `BuildTimeoutSec` 已抬到 **7200 s**，但仍可能不够 ⇒ **建议直接给 4 小时**
- 判据：`sim/evidence/gowin_m0_timing.txt` 里 **0 setup / 0 hold**

---

## 二、本轮做完的四件事

### 2.1 效果器参数从编译期常量改成运行时寄存器

**改之前**（合并队友 fx 分支后的状态）：

```verilog
top.v:57-66    FX_EN_MASK / FX_DIST_GAIN / ... 全是 parameter
top.v:6029     if ((FX_EN_MASK[2:0] != 0) || (FX_TREM_DEPTH != 0)) begin : g_fx
uart_ui:208    fx_en_o <= 1'b0;  fx_sel_o <= 2'd0;   // 恒 0，不解析任何效果器变量
```

问题：`mask = 0` 时**整条链根本不综合进去**，只剩旁路 ⇒ 运行时发什么都进不了
效果器；且改任何参数都要重新综合 + 重新 PnR（几十分钟一轮）。

**改之后**：

| 文件 | 改动 |
|---|---|
| `rtl/w3c/uart_ui.v` | 删掉 `fx_en_o`/`fx_sel_o`（恒 0 的留位），加 **9 个运行时寄存器 + `fx_commit_o`**；`RET_NUM` 分支加 `0x10..0x18` 解析；加 9 个 `FX_*_DEF` parameter 做上电初值 |
| `rtl/top.v` | `g_fx`/`g_fx_bypass` 的**编译期 generate 改成无条件例化**；参数全部接 `uart_ui` 的运行时寄存器；`uart_ui` 例化透传 `FX_*_DEF` |

**为什么保留 `FX_*_DEF` parameter**：队友的 `tb_top_fx_audio` 会编译期覆盖
`FX_EN_MASK=8'hFF` 做全开档验收 ⇒ 透传之后**判据不用重写**。

### 2.2 零回归口径更新（必须知道）

```
旧口径 = 输出【逐拍】相同
新口径 = 输出【逐样本】相同，整体延迟 19 拍（380 ns @50 MHz）
```

原因：无条件例化 `fx_chain` 才能运行时控制，代价是旁路时也走那 19 拍。
380 ns 相对音频周期 20.5 µs 是 **1.9%**，听不出来。

### 2.3 顺带修出一个真健壮性缺陷

```
症状：发 `71 10 FF FF FF`（想把掩码设成 0xFF）
  0xFF 是帧尾标记 ⇒ 不计入 body_len ⇒ body_len 只到 1
  而帧尾一到【照样落地】⇒ 把【上一帧遗留的陈旧 val_q】写进了寄存器
```

不只是"设不进去"，而是**写入了垃圾值**（用户会看到参数莫名跳变）。

**修法**：`RET_NUM` 加闸门 —— `body_len < 2` 时一律不落地。
- 零回归：既有的合法用法（`71 01 18`）`body_len` 恰好 = 2
- 只对 `RET_NUM` 生效 —— `0x65`（触摸）本来就是 1 字节帧，不能加这个限制

### 2.4 判据与工具

| 文件 | 内容 |
|---|---|
| `tb/w3c/tb_uart_ui.sv` | +20 条（9 个变量的解析 / 换算 / 饱和 / 负向 / `0xFF` 契约）；新增 `feed_frame_z`（严格版） |
| `tb/w3c/tb_evt_uart_rx_gate.sv` | 新端口改成悬空 |
| `tools/fx_ctrl.py` | 串口控制工具（含 `sweep` 增益扫描） |

**为什么新增 `feed_frame_z`**：原来的 `feed_frame` 在 `body1 == 0` 时不发第二个
字节 ⇒ **永远测不到"值 = 0"那一档**，而 0 是合法值（`depth = 0` 就是旁路判据）。

---

## 三、串口控制速查（上板用这个）

### 3.1 接线与参数

```
引脚：uart_rx = D14（助手 TX → FPGA）· uart_tx = D15（FPGA → 助手 RX）
参数：500000 8N1
```

**注意**：这条串口与**串口屏共用**。两者靠"字节形态"区分（屏是 TJC 帧、
命令是单字母），不冲突。但物理上共用一根 RX 线 ⇒ **两个都在发就会撞** ⇒
插助手时把屏拔掉（或反过来）。

### 3.2 帧格式

```
<返回码> <变量序号> <值> FF FF FF
   0x71      0x10..0x18
```

效果器变量表：

| 序号 | 名字 | 值域 | 换算 | 说明 |
|---|---|---|---|---|
| 0x10 | mask | **0x00..0x07** | 直传 | bit0=失真 bit1=合唱 bit2=延迟 · ⚠️ **bit4 不是颤音**（见 §3.5）· ⭐ 全开 = **0x07** |
| 0x11 | gain | 0..254 | ×256 ⇒ Q4.12 | 失真增益：32⇒2.0 · **64⇒4.0（默认）** · 254⇒15.875 |
| 0x12 | trim | 0..254 | ×256 ⇒ Q1.15 | 失真补偿：**32⇒0.25（默认）** · 128⇒1.0 |
| 0x13 | mix | 0..254 | 直传 Q0.8 | 延迟/合唱混合 |
| 0x14 | fb | 0..254 | 直传 Q0.8 | 延迟反馈 |
| 0x15 | depth | 0..254 | 直传 | 颤音深度，0 = 数值恒等 |
| 0x16 | rate | 0..254 | 直传 | 颤音速率 |
| 0x17 | dlylen | 0..254 | ×128 采样 | 延迟长度：64⇒8192（168 ms），**>127 饱和到 16383** |
| 0x18 | chorlen | 0..254 | ×32 采样 | 合唱长度：23⇒736（15 ms），**>63 饱和到 2047** |

掩码速查：

```
0x00 全关          0x01 只失真        0x05 失真+延迟
0x07 失真+合唱+延迟  ⚠️ 0x17 与 0x07 **等价**（bit4 空转，⛔ 不是"含颤音"）
```

### 3.3 用工具（推荐）

```bash
python tools/fx_ctrl.py --port COM31 list        # 看全部变量
python tools/fx_ctrl.py --port COM31 on          # 全开（0x07 = 失真+合唱+延迟）
python tools/fx_ctrl.py --port COM31 off         # 全关
python tools/fx_ctrl.py --port COM31 mask 0x05   # 只要失真+延迟
python tools/fx_ctrl.py --port COM31 gain 64     # 失真 4.0 倍（默认档）
python tools/fx_ctrl.py --port COM31 drive 64    # ⭐ 归一化驱动（gain 64 + trim 32，推力↑音量不变）
python tools/fx_ctrl.py --port COM31 depth 96    # 颤音开
python tools/fx_ctrl.py --port COM31 sweep       # 增益扫描（找明显失真的点）
python tools/fx_ctrl.py --port COM31 raw 10 17   # 发任意帧体（⛔ 不带返回码 0x71）
```

### 3.4 用串口助手手动发（HEX 模式）

```
71 10 07 FF FF FF     失真+合唱+延迟（⭐ 这才是"全开"；⚠️ 0x17 出声相同但 bit4 空转）
71 11 40 FF FF FF     失真增益 64 ⇒ 4.0 倍（⭐ 默认档）
71 11 FE FF FF FF     失真增益 254 ⇒ 15.875 倍（最大）
71 12 20 FF FF FF     失真补偿 32 ⇒ 0.25（⭐ 默认档）
71 10 00 FF FF FF     全关
```

### 3.5 两个必须知道的约束

**约束一：值 0xFF 不可用。** 它是帧尾标记（`FF FF FF`），协议固有约束。
- 实用影响很小：掩码只用 **bit 0/1/2** ⇒ ⭐ **全开 = `0x07`**，**永远不需要 0xFF**
- 要"全开"用 `0x07`；要"差一位"用 `0x06`（少失真）/ `0x05`（少合唱）/ `0x03`（少延迟）
- ⚠️ **`0xFE` ⛔ 不是"差一位"** —— 它是 **bit0 清零 = 把失真关掉**（⭐ 只剩合唱+延迟），
  与"全开差一位"**无关**（⭐ 旧版本这里写错过，见 2026-10-15 修正）
- 工具会**主动拒绝** `0xFF`，不会静默发出去

**约束二：值只有一个字节。** 所以增益只能表达 **256 的整数倍**。
- 值 64 ⇒ 16384（4.0 倍），这是默认
- 想精确写 Q4.12 原值请用 `gain-raw`，它会提示最接近的那一档
- ⭐ **`drive <值>`** 一次发两帧（`gain = 值` + `trim = round(2048/值)`）⇒
  ⭐ **推力↑而音量不变**；对照表 `16→128 · 32→64 · 64→32 · 128→16 · 254→8`
  ⚠️ **`254→8` 那一档的净增益是 `254×8/2048 = 0.9921875`**（⭐ 差 0.78%，听不出来），
  ⛔ **不是正好 1.000** —— ⭐ 因为补偿字节只能取整（`round(2048/254) = 8`）✅

---

## 四、待办

| # | 事项 | 说明 |
|---|---|---|
| 1 | **PnR 跑完** | 判据：`sim/evidence/gowin_m0_timing.txt` 里 0 setup / 0 hold |
| 2 | **全量回归** | `powershell -File sim\tb_all.ps1` ⇒ 判据是"通过 N / 共 N"且 N 相等 |
| 3 | **上板验收** | 见下节"上板验收清单" |
| 4 | **推送** | 需用户同意；按项目规则先 `reset --soft origin/main` 压成 1 个提交 |
| 5 | 串口屏上的效果器页 | 未做 —— 现在只有帧协议，屏上还没有控件 |
| 6 | 混响 | 只留位直通，未实现（符合当前分期） |

### 上板验收清单

```
1. 烧完先别发任何帧 ⇒ 应该和"没有效果器"听起来一样（零回归）
2. python tools/fx_ctrl.py --port COMxx on        ⇒ 灯 7 应该亮
3. 按住一个音，逐个发：
     mask 0x01  ⇒ 只失真（应该明显"破"）
     mask 0x02  ⇒ 只合唱（应该变宽）
     mask 0x04  ⇒ 只延迟（应该有回声）
     mask 0x10  ⇒ ⚠️ **什么都不做**（bit4 空转）—— ⭐ 要听颤音必须先 `depth 96`
4. 如果失真"听不出来" ⇒ 跑 sweep，从 32 扫到 254
     失真够不够取决于增益能不能把信号推过满量程
5. mask 0x00 + depth 0 ⇒ 回到干声
```

---

## 五、已知问题与坑

### 5.1 效果器模块自身的 13 处问题（队友已修，见复盘文档）

**根因**：我把乘积打了拍（`p1`/`p3`），但下游用的是**组合版**（`prod1`/`prod2`）
⇒ 数据路径比 valid 路径短一拍 ⇒ 输出样点与自己的 valid 错拍。

最严重的后果：**单位增益恒等契约失效**（`gain=1`/`trim=1` 时 valid 输出 0）。

**为什么我的判据没抓到**：我只"数 valid 条数"，没做逐样本比对。
队友的原话：*"撤掉 valid 后保持 sample ⇒ 数据提前数拍仍可能绿。"*

队友的 `tb_fx_public_contract` / `tb_fx_clip_valid` 已合进仓库 ⇒ 这两类问题
从此会被自动抓到。

### 5.2 资源预算的基线

```
❌ 我原来写的：BSRAM 69 + 18 = 87/118 = 74%
✅ 队友指出：BJ 基线【已经是 83 块】
   ⇒ 按独立综合 20 块相加，应该约 103/118
```

⚠️ 队友也说了*"是否真为 103 须完整综合映射核验"* ⇒ **最终答案只能来自一次
完整的 PnR**。别引用旧的 69 那个数。

### 5.3 `.gprj` 注释里有 11 个非 ASCII 块

项目规则说 `.gprj` 注释只放 ASCII，但队友这次加了 11 个含中文的注释块。
他的构建能过（综合 0 ERROR 已证实），所以暂不动它 —— 但**改 `.gprj` 时要留意**。

另外两条 `.gprj` 硬约束（都踩过）：
- 注释正文里**不许出现连续两个连字符 `--`** ⇒ Gowin 报 `invalid project file`
  且不给行号
- `.gprj` 里 `fx_` 必须与 `top.v` 的例化**同时改**，否则 `NL0002` 会扫掉

### 5.4 工具类的坑

| 坑 | 现象 | 解法 |
|---|---|---|
| `edit` 工具剥掉 `.ps1` 的 BOM | `check_ps1_encoding.ps1` 报 FAIL | 改完 `.ps1` **立刻**查；用 `add_ps1_bom.ps1 -Apply` 修，然后回退多余的文件 |
| Windows 控制台是 GBK | Python 脚本里的 `⇒` 直接崩 `UnicodeEncodeError` | `chcp 65001` + `sys.stdout.reconfigure(encoding="utf-8", errors="replace")` |
| Python 字符串里用 ASCII 引号 | 把字符串截断 ⇒ `SyntaxError` | 用中文引号或「」 |
| `Get-Content` 读无 BOM 的 UTF-8 中文 `.v` | 按 GBK 解码 ⇒ 非 ASCII 吃掉换行 ⇒ 行被合并、行号全错 | 用 `[IO.File]::ReadAllLines(...)` 或 `read` 工具 |
| 回归里报 `TIMEOUT after 120 s` | 可能只是预算太紧，不是真挂死 | 看驱动器提示"日志里已出现 PASS:"；看 `sim/evidence/<tb>.log` 里有没有 `PASS:` |

---

## 六、文件索引

### 本轮改的

```
rtl/w3c/uart_ui.v          效果器运行时寄存器 + 0x10..0x18 解析 + body_len 闸门
rtl/top.v                  fx_chain 无条件例化 + 参数接运行时寄存器
tb/w3c/tb_uart_ui.sv       +20 条判据 + feed_frame_z
tb/w3c/tb_evt_uart_rx_gate.sv   新端口悬空
tools/fx_ctrl.py           串口控制工具
files/20-代码/效果器复盘-20261015.md    队友改了我 13 处
bringup/27-交接-FX运行时控制-20261015.md   本文
```

### 效果器相关（队友的）

```
rtl/w3c/fx_chain.v · fx_dist.v · fx_trem.v · fx_delay.v
tb/w3c/tb_fx_chain.sv · tb_fx_dist.sv · tb_fx_trem.sv
tb/w3c/tb_fx_chain_latency_contract.sv
tb/w3c/tb_fx_dist_stream_contract.sv · tb_fx_trem_stream_contract.sv
tb/w3c/tb_fx_delay_production.sv
tb/top/tb_top_fx_audio.sv
review/fx-version-review-20261015.md
bringup/26-FX顶层版-功能上机手册-20261015.md
```

### 规格与设计

```
files/20-代码/效果器链-整合方案-20261014.md     设计与分期
files/20-代码/ESP32侧需求-0xABF1加WRITE位-20261014.md
files/20-代码/ESP32侧需求-STAT周期性notify-20261014.md
```

---

## 七、一句话交接

> 效果器**已经能上板实时调**了：烧完先确认"全关时听起来和以前一样"，
> 然后用 `tools/fx_ctrl.py` 或串口助手发 `71 10 07 FF FF FF` 全开。
> **失真听不出来就扫增益** —— 它取决于增益能不能把信号推过满量程。
> PnR 还在跑，出结果后补全量回归。
