hokuu1102/Gowin2026-PolySynth/bringup/29-本轮改动方向书与进度-20261015.md

# 本轮改动方向书 ＋ 进度账（2026-10-15 夜）

> **基线（改动前的绿色交付点）**：PnR **0 setup / 0 hold** · `Fmax 61.067 MHz` · 回归 **通过 204 / 共 204**
> 位流：`evidence/fx_splitcone_20261015/Gowin2026_splitcone_61.1MHz.fs` · sha256 `5F07A204…543B`
> ⇒ ⭐ **任何一步出问题都能退到这个点** ✅
> **纪律**：⭐ 先 PnR（独占）⇒ 再全量回归（⛔ 两者不并发，会假超时）· ⛔ 不动 `.ps1`（BOM 陷阱）· `.md`/源码保持 **LF**

---

## 一、七项任务的方向与状态

### ① 方案 B（鼓机多声部）—— ⭐ **RTL + 判据已完成并验证能红**
- **判据**：`seq_arb.v` 的 `score_axis_i >= 4'd12 ⇒ SRC_KDRUM`（⭐ 与 ESP32 侧**逐字符一致**）
- **ESP32 侧要求的三条**（`ESP32侧确认-方案B已改完请出位流-20261015.md` §五）：
  - 轴 15 ⇒ `SRC_KDRUM(5)` ✅ · 轴 12/13/14 ⇒ `SRC_KDRUM(5)` ✅ · ⭐ **轴 11 ⇒ `SRC_SCORE(1)`**（边界非空洞性）✅
- ⭐ **"能红"已实证**：阈值故意写成 `>= 4'd11` ⇒ `FAIL: axis==11 … OFF BY ONE` ＋ **退出码 1**，已还原复核回绿 ✅
- ⭐ **补的缺口**：FPGA 侧原来**没有**判据验"轴 12/13/14/15 各带正确的 `inc`" ⇒ 四件鼓身份全靠 `inc`（`note_manager.v:956-957` 按 `inc` 分档）⇒ ESP32 配错也全绿 ⇒ 已补 4 条（单一来源取 `drum_gen.INC_*`）
- **回归面**：⭐ 驱动 `score_axis_i` 的 4 支 tb 取值**全 < 12** ⇒ 无既有 tb 变红 ✅
- ⚠️ **ESP32 引用的行号过时**：他们写 `seq_arb.v:204`，实际在 **`:212`**（注释推后 8 行）
- 📄 遗留风险见 `files/20-代码/鼓机方案B-遗留风险-20261015.md`

### ② P0-4 拨弦双触发 —— 🔄 施工中
- **根因（逐拍表已钉死）**：`async_pluck_capture.v:81` 的 `armed_q <= both_low;` 是**锁存状态**，⛔ 不是 `both_low` 的组合函数 ⇒ 回中**穿过**中位 1 拍（20 ns）就重新武装 ⇒ **110 ms 后的回摆过冲照出第二个音**
- **修法**：新增 `CENTER_HOLD_CYC = 1_000_000`（20 ms）+ `center_q` 计数器 + `rearm = both_low && (center_q == CENTER_HOLD_W)`；⭐ **`center_q` 复位 = 满**（与 `armed_q` 复位 1 一致，否则凭空多 20 ms 吞拨窗口）；⭐ **独立 always 块**（避免 `EX2000` 多驱动）；`:89` 的 `armed_q <= 1'b0` **保留**（变防御性冗余）
- ⭐ **为什么不加长 `REFRACT_CYC`**：回摆过冲 100~300 ms 与**有意慢拨** 200~250 ms **区间重叠** ⇒ **不存在能分开两者的 refractory 值**（维度不够）✓
- 🔴 **旧 tb 判据是【结构性空洞】的**：把 DOWN 落与 UP 起放在**同一个 negedge** ⇒ `both_low` **从未为真** ⇒ 门控全程撤防 ⇒ **恒绿，根本抓不到这个 bug** ⇒ 新判据必须复现**真实**序列
- ⚠️ **`armed_o`/`both_low_o` 顶层悬空** ⇒ 综合剪掉整锥 ⇒ 已照 `top.v:1602` 的 `syn_keep` 先例接上（⭐ 但 `syn_keep` 只保**网线**，真能读仍需**消费者**）
- ⭐ **硬件侧（与软件互补，⛔ 不是替代）**：`右手板方案.md:342` 的迟滞 `R5`/`R6` = **470 kΩ**（正反馈到非反相端）⇒ 迟滞宽度 `ΔV = 3.3 × (R1‖R2)/(R1‖R2 + 470k) ≈ **40 mV**`（≈0.8° 行程）
  - ⭐ **但迟滞治不了 P0-4**：迟滞治"**同一阈值上的抖动**"（µs 级），而 P0-4 是"**机械回摆从 DOWN 侧穿到 UP 侧**"（**110 ms，两次真实穿越**）⇒ ⭐ **原理上管不到** ⇒ **软件门控是唯一正确的修法** ✓
  - ⚠️ `右手板方案.md:415`：阈值必须围 `V_rest` **对称**摆（⛔ 不能按 1.65 V 算）· 换算 **每 0.1 V = 345 Ω**（`:424`）

### ③ 延迟 mix 律 —— ✅ **完成**
- **病因**：`fx_delay.v` 原用 **crossfade** `y = dry×(1−mix) + wet×mix` ⇒ `mix=128` ⇒ **干声被砍到 50%（−6 dB）** ⇒ 开延迟 = "原音变小 + 突然多一声回声" = 用户说的**"突兀地响两下"**；🔴 且**合唱与延迟共用同一 `mix`/`fb`** ⇒ 串联后**干声只剩 25%（−12 dB）**
- ⭐ **修法（功能面只有 1 行）**：`fx_delay.v:272` `dry_w = ONE_Q`（原 `ONE_Q − mix_u`）
  - ⭐ 等价性：`(dry×256 + wet×mix) >>> 8 ≡ dry + ((wet×mix) >>> 8)` **逐位相同** ✓
  - ⭐ **`mix=0` 仍逐位恒等**（契约不破）✓ · ⭐ 附带 **省一个 24×9 乘法器**（`p_dry` 退化成 `dry_s3 << 8`）✓
  - ✅ **未动** `SUM_W`（`:105` = `SAMPLE_W+MIX_W+2` = **34**）· 未动出口饱和
- **合唱 fb 独立**：`fx_chain.v:236` `.fb_i({FB_W{1'b0}})` ⇒ 15 ms 共振梳状消失
- **tb**：只有 `tb_fx_delay_production` 的 `offset==0`（9/18/27 **未动**）· `tb_fx_chain` C4a/`:245`；⭐ **`tb_fx_chain_latency_contract` 免疫**（`en_mask=0` 旁路）
- ⭐ **新增 2 条判据 + 变异实证**（在 `$TEMP` 副本上做，⛔ 仓库 RTL 未动）：**C12**（合唱忽略 fb；对照延迟必须不同）· **C13**（`mix=0` 逐位恒等 —— 补上**空洞契约**）
- ⚠️ **饱和账**：最坏同相 `1.5×dry`（mix=128）/ `~2×`（mix=255）⇒ 出口饱和**可能开始触发**（有界、不回绕）；按单音峰 24.9% FS 推：单音 ≈37% FS、两音同相 ≈75% FS ⇒ ⭐ **当前电平不削顶** ✓
- ⚠️ **"上电音色会变"要打折扣**：`top.v:57 FX_EN_MASK = 8'd0` ⇒ ⭐ **上电 mask=0、FX 全旁路 ⇒ 音色不变**；真正变的是**打开效果那一刻**（开合唱 ⇒ 梳状消失；开延迟 ⇒ 干声回到 ×1.0 = **+6 dB**）

### ④ 失真驱动量程 —— ✅ **完成**
- **量化账（用户实测交叉验证）**：干声 **1/8 FS = 0.125**；削顶需净增益 ≥ **8.0×**；旧上限 = `7.9375 × 0.99219` = **7.8755×** ⇒ **差 1.6%** ⇒ 峰值 **98.4% FS** ⇒ ⭐ **"差不多到顶，只削了一点点顶"逐字吻合** ✓
- ⭐ **修法**：`uart_ui.v:393/398` `{val_q,7'b0}` → **`{val_q,8'b0}`**（×256）⇒ 上限 **15.875 × 1.9844 = 31.5×** ⇒ 干声 1/8 FS 下 **~83% 周期削平** = 真方波
- ✅ **无截断**（`{val_q,8'b0}` 恰好 16 位，255⇒`0xFF00`=65280 ≤ 65535）· ✅ **无溢出**（`SUM1_W=SUM2_W=SAMPLE_W+16=40`）· ✅ **零回归**（复位走 `FX_*_DEF` 参数，**不经映射**）
- 🔴🔴 ⭐ **必须记住的数**：**默认档 `(128,64)` 的语义从 1.0× 变成 4.0×**；⭐ **想复现"上电默认"要发 `(64, 32)`**（`FX_GAIN_DEF=16384`→64 · `FX_TRIM_DEF=8192`→**32**）
  - ⚠️ 施工队纠正了我一个算错的数：我原说 `(64,64)` ⇒ 那会得 **2.0×**，⛔ 不是 1.0×
- **tb**：`tb_uart_ui` 5 条 golden（`:333→8192` `:336→32768` `:346→65024` `:350→32768` `:390→65024`）· ✅ 复位断言 `:233-234` **未动**
- **工具**：`fx_ctrl.py` 新增 **`drive`** 命令（一次发两帧：`gain=值` + `trim=round(2048/值)`）⇒ ⭐ **驱动↑而音量不变**；⚠️ 值 ≤8 时 `trim` 需 >254 ⇒ **饱和到 254 + 显式告警**（⛔ 不静默）；值 0/255 拒绝
- **文档**：`bringup/27` + `bringup/28`（⭐ `bringup/26` 与 `上机手册-20261014` **grep 0 命中 ⇒ 不是目标**）· ⚠️ `mix` 行留给 ③

### ⑤ 键盘新键"一键恢复默认音高" —— 🔄 施工中
- **键位**：⭐ **列 2 / 行 3** ⇒ `key = row*4 + col` = **key 14** = 布局表里的 **"备用 2"**，⭐ 正好在**列 2 · 音高组** ⇒ 语义完美
- **原理**：`fader_gear.v` 已有 `trans_abs_i` + `trans_abs_val_i[7:0]`（⭐ 编码 0..24，⭐ **12 = 不调**）⇒ `transpose_semi_o = enc_r − 12` ⇒ ⭐ **复用现成通路送 `8'd12`**，⛔ 不用改 `fader_gear.v`
- **改动**：`ctrl_key_map.v` 加 `trans_reset_req_o` + `if (key_down[14]) …`；`top.v` 把 `trans_reset_req` OR 进 `trans_abs_i` 并 mux 出 `8'd12`（⭐ **必须与 `trans_abs_i` 同拍**）
- ⚠️ 🔴 **`ctrl_key_map.v` 有 `EX2000` 前科**（同一 `reg` 在两个 always 块里赋值 ⇒ 仿真全绿、综合才炸）⇒ ⭐ 新信号**只能在一个 always 块里写**

### ⑥ 指板多轴拨弦（用户拍板 A 方案）—— 🔄 施工中
- **用户症状**：⭐ **"指板模式还是只有一个音，所以滑音也测不出来"** ⇒ **用户已确认要 A = "一次拨弦出和弦"**
- ⭐ **真根因**：`play_mode_ctrl.v:47-58` 的拨弦分支用 `pluck_found`/`rot_q` 在 `held_mask` 上**轮转扫、命中即停** ⇒ **一次拨弦只出一条 PLUCK**
- ⭐ **这是【已文档化的取舍】**（`tb_play_mode_ctrl.sv:151-159` 逐字）："一次拨弦 ⇒ 触发一个轴…与 **P0-22 ①** 契约冲突 ⇒ 取舍：保住零回归 ⇒ 🔴 代价：一次拨弦出和弦做不到 ⇒ 📌 若将来要 ⇒ **必须先重谈 P0-22 ① 的契约，⛔ 不能偷偷改**"
  - ⇒ ⭐ **用户已拍板 ⇒ 授权变更** ✓ ⚠️ 但**必须在注释/回报里明确写"经用户授权的契约变更"**
- ⛔ **指板是"一键一轴"（16 键 16 轴）**（`axis_map.v:541` 扁平 16 项查表；`tb_axis_map.sv:293` 守着"16 轴音高各不相同"）⇒ ⛔ **别去动 `note_manager` 的 `same_hit`**（`note_manager.v:869-875` 把"每个 `(axis,src)` 同时最多 1 个 voice"写成**显式设计不变量**）
- ⭐ **有利条件**：`keyboard_held[]` 位图已在做**逐轴释放** ⇒ 当初逼出"一次拨弦一个轴"的 P0-22 ① 冲突**结构上已基本消解**
- **判据**：🔴 M2 现在断言"一次拨弦一个轴" ⇒ **必须按新契约改**；⭐ 新增"按 3 轴 ⇒ 拨一次 ⇒ 3 条 note_on（各有配对 note_off）"· "按 1 轴 ⇒ 仍只 1 条"· "按 16 轴 ⇒ 16 条"；⭐ **M4/M5 必须仍绿**

### ⑦ 文档 / 换算表同步 —— 🔄 随各队落地
- `bringup/27` · `bringup/28` · `tools/fx_ctrl.py` · `files/20-代码/控制板16键功能映射-20261013.md`（⑤ 的行 3 列 2）
- ⭐ 新建：`files/20-代码/鼓机方案B-遗留风险-20261015.md`（①）

---

## 二、⭐ 全局必知的数字（⛔ 别记错）

| 项 | 值 |
|---|---|
| 链延迟 | ⭐ **19 拍**（拆锥后：`fx_delay` 4→5 级 × **两个实例** ⇒ 17→19）· 380 ns |
| 默认档语义 | ⭐ `(128,64)` 从 **1.0×** 变成 **4.0×**；⭐ **复现上电默认要发 `(64, 32)`** |
| 失真上限 | **31.5×**（原 7.8755×）· 干声 1/8 FS ⇒ ~83% 削平 |
| 延迟律 | ⭐ **send/return**（`dry + wet×mix`）· `mix=0` 逐位恒等 |
| 合唱 | ⭐ **无反馈**（`fb=0`）· 15 ms 共振梳状消失 |
| P0-4 门控 | ⭐ **中位持续 20 ms**（`CENTER_HOLD_CYC=1_000_000`）才重新武装 |
| 键盘新键 | ⭐ **key 14**（列2行3）⇒ 音高归零 |
| 鼓轴 | ⭐ **12/13/14/15 = 四件鼓**；旋律轴 **0..11** |

---

## 三、⏭ 剩余步骤（⭐ 顺序固定）

```
1. 等 ① ② ⑤ ⑥ 施工完成（含各自的"能红"实证）
2. ⭐ 第二轮 agent team：逐模块 bug 排查（⭐ 用户要求"查得明明白白"）
3. ⭐ PnR（独占 CPU）—— 判据：0 setup / 0 hold ＋ 位流存在
4. ⭐ 全量回归 —— 判据：通过数 == 共数（⛔ 不写死数字）
5. 出位流给 ESP32（带方案 B 的鼓修改）＋ 转 §六 联调清单（4 条判据）
```

## 四、⚠️ 已知未修 / 待议（⛔ 别当成"已解决"）

| # | 内容 | 状态 |
|---|---|---|
| ① | `key_drum_r` 覆盖谱面四件鼓的 `inc`（串口 `'K'` + 灌谱 ⇒ 四件全变踩镲） | ⭐ **用户裁定：先不修**，已记档 |
| ② | 同根：`key_drum_r=1` 时谱面**旋律也变鼓**（改前就存在） | 记档 |
| ③ | `RESERVED_N=5` = 四件鼓 + 源B ⇒ 第 6 个鼓声部抢占 | 记档（只静态核算） |
| ④ | `guide_lamp` 把四件鼓**全指到踩镲垫**（灯而已） | 记档 |
| ⑤ | 灯 7（效果器）**颜色映射不可信**（P1-6：位掩码当枚举下标） | ⭐ **未修**（纯装饰） |
| ⑥ | 干声 **1/8 FS（−18 dB）** 的增益结构问题 | ⭐ **未修**（会牵动所有电平判据） |
| ⑦ | `primed` 后湿声**硬台阶**（`fx_delay.v:242`，无淡入）⇒ 若"突兀"仍在先查这条 | ⭐ **未修**（P2-38，tb 结构上抓不到） |

---

## 五、⭐⭐ 第二轮排查（六路）的发现与修复队列（2026-10-15 深夜）

### 5.1 🔴 三个新 RTL 缺陷（鹰眼 HAWKEYE 抓到，⭐ 其中两条造成挂音）

| # | 缺陷 | 机理 | 修法 |
|---|---|---|---|
| **1** | 🔴 **FSM 快照 + FSM 中途 `KIND_OFF` ⇒ 为已松开的轴发 PLUCK ⇒ 挂音** | `:276 pluck_todo <= pluck_rest` 用**快照**，而 `:188-189` 的 OFF **只清 `held_mask`，⛔ 不清 `pluck_todo`** ⇒ FSM 窗口内被松开的轴仍被逐拍发 `PLUCK` ⇒ `:284` 给**没按住**的轴置 `keyboard_held`，而它的 OFF **已用掉** ⇒ **永无配对 OFF** | `:188-189` 旁加 `pluck_todo[axis_i] <= 1'b0;` |
| **2** | 🔴 `axis_clr_i` 不清 `pluck_run`/`pluck_todo`，`pluck_begin` 也不屏蔽它 | 掉沿那拍 FSM 在跑 ⇒ 仍按脏快照发 PLUCK | 同拍清两者 + 把 `axis_clr_i` 加进 `pluck_begin` 屏蔽项 |
| **3** | 🔴🔴 **`axis_clr_i` 修了 `held_mask`，⛔ 没修 `keyboard_held`** ⇒ **永久挂音** | 按住轴→按 `'T'`→`enable_i=0` 期间松手 ⇒ 自愈 ON 也不发（`pos<TRIG_TH`）⇒ `keyboard_held` 永久 1，而全部 OFF 出口都要求**先收到 OFF** | 掉沿时对仍置位的轴**逐拍补发 OFF**（走 `evt_*` 单口，≤16 拍）· ⛔ 不可直接清 `keyboard_held` · ⛔ 不可在 `event_extract` 里同拍补 16 条（挤爆 `FIFO_D=4`） |

⚠️ **症状升级**：缺陷 3 把"多一个音"变成"**永久挂音**"—— 比原症状更严重 ✓

### 5.2 🔴 判据空洞（⭐ 没有能红判据的修复不算数）

| 空洞 | 现状 | 补法 |
|---|---|---|
| **H1** 无"轴事件落在 FSM 窗口内"用例（⭐ 掩盖缺陷 1） | 去掉 `:137` 的 `!axis_valid_i` ⇒ **全绿** | 按住 {1,2,3} ⇒ 拨弦 ⇒ 第 2 拍插 `axis_evt(2,OFF)` ⇒ 断言事件数 + `keyboard_held` 里无已松轴 |
| **H2** `axis_clr_i` 优先级无覆盖 | `:183` 挪到 `:189` 后 ⇒ **全绿** | `axis_clr` 与 `axis_evt(9,ON)` **同拍** ⇒ 随后拨弦 ⇒ 断言恰好 1 条且 `axis==9` |
| **H3** `axis_clr_i` 与 FSM 同拍无覆盖 | 不清 `pluck_run`/`pluck_todo`（现状）⇒ **全绿** | 掉沿时 FSM 在跑 ⇒ 断言**不为脏快照发事件** |
| **H9** ⭐ **"删门控"零覆盖** | `tb_async_pluck_capture.sv:113-129` 的替代用例**带门控也全绿**（两条拨弦之间都回到"两路都低" ⇒ `armed_q` 会重新武装） | `down_async=1` **保持** + 耗完 refractory ⇒ 再给一个 `down` 新沿 ⇒ 断言**仍出声**（⭐ 带门控必红） |
| **H10** `armed` 无任何断言 | `:82 armed_o = 1'b0` ⇒ **全绿** | 断言 `armed_o === 1'b1` |
| **H4/H5**（低优先） | 零轴拨弦 · 轴顺序 | 可选 |

### 5.3 🔴 判据真缺陷（熔炉 FORGE 逐行核实）

| 位置 | 缺陷 |
|---|---|
| `tb_uart_ui.sv:468` | ⭐ `err_cnt > 0` **恒真** —— `feed_frame_z` 无条件发 body1 ⇒ `:405` 实际发 6 字节/4 个 `0xFF` ⇒ 第 4 个 FF 落 `S_IDLE` 时 `err_cnt` **已**是 1 ⇒ 改成存 `e_before` + 断言 `=== e_before+1` |
| `tb_uart_ui.sv:484` | `%0d checks` **写死 28**（实际 **65** 条）⇒ 改成运行期计数 |
| `tb_uart_ui.sv` | ⭐ **`mask = 0` 从未被任何帧写过** ⇒ 补一条（抓"只能置位不能清零"） |
| `uart_ui.v:450` | 🔴 `body_q <= rx_data_i[6:0]` **丢最高位** ⇒ `0x90→0x10` ⇒ `71 90 05 FF FF FF` **静默写 `fx_mask=5`** |
| `tb_seq_arb.sv` 4 条 inc 判据 | 🔴 **量纲错**：`top.v:4844` 是 **21 位字段 `<<10`**，而 `drum_gen.INC_*` 是 **23~28 位满量程** ⇒ 生产值只能是 `(INC_*>>10)<<10`（差 901/41/163/273）⇒ 今天绿只因 tb 绕过 `top.v` ⇒ ⭐ **"已补缺口"不成立**；⭐ 行号 `4740` → **`4844`** |
| `tb_seq_arb.sv` | 🔴 **10 条判据全部只驱动 `kind=0`** ⇒ 鼓的 `note_off`(kind=1) 是否带 `SRC_KDRUM` **无人验** ⇒ 若标错 ⇒ `note_manager.v:1320` 让鼓 voice **永久 held** ⇒ 池子耗尽 |

### 5.4 `tools/fx_ctrl.py` + 文档缺口（14 条，挑最要紧）

- 🔴 ⭐ **`top.v:1165` `ui_fx_en = |ui_fx_mask` 仍把 bit4 或进去** ⇒ **`mask 0x10` 会点亮灯 7 却什么都不做** · `uart_ui.v:135`/`top.v:1221` 的 `bit4=颤音` **都还在** ⇒ **P0-2 只修了一半**
- 🔴 `describe_mask` 自相矛盾（`BIT_TREM=4` 仍打印"0x17 含颤音"）· `--strict` help 仍"128 倍数" · `drive` 死分支 `:292-293` · `gain-raw` 的 0xFF 检查**误拒** `gain-raw 255` + `hi==0xFF` 死条件 · `//256` 与"最接近"（floor vs round）
- 🔴 `bringup/27:174` + `fx_ctrl.py:124` 的 **`0xFE` 坏建议**（`0xFE` 是**把失真关掉**）· `:18` 悬空引用 · `:19` PnR 状态过期
- 🔴 ⭐ **`×256` 不在 21:07 的位流里**（`uart_ui.v` 22:31 > 位流 21:07）⇒ **必须重跑 PnR** 才能宣称"×256 版已验证"
- ⚠️ ⭐ **`×256` 是【静默的接口破坏】**（老字节值现在 = 4.0×），而协议**没有回读通路** ⇒ 用户分不清烧进去的是哪版映射

### 5.5 ⚠️ 其他要点（磐石 BEDROCK / 钥匙匠 LOCKSMITH）

- ⚠️ **风险文档 `鼓机方案B-遗留风险-20261015.md` 的 `top.v` 行号全错** ⇒ 正确是 **5379 / 5384-5387 / 5401 / 5413 / 5448 / 5686 / 6617-6619**
- ⚠️ **`RESERVED_N`：默认档不会抢占**（4+1=5 恰好满、第 6 个不可达）⇒ ⭐ **比风险文档更安全** ✓
- ⚠️ 旋律落轴 12-15 **无护栏、静默变鼓**（K-106 家族）· `base_oct_r` 会改鼓的 kick/tom 分档
- ⚠️ `-Filter M14` 现命中 3 条（M14/M140/M141）· `mutation_test.ps1:500` 的"All 133 IDs"过时（现 135）
- ⚠️ `tb_top_ctrl_wire.sv:103` 判据名被截到最后 64 字符（`***` 被吃掉）· `:373` 预算余量仅 45%
- ⚠️ `top.v:2837-2842` 的仲裁注释**只写 `'H'`**，漏了 `'F'`/`'G'`/EC11 会赢过键 14
- ✅ **钥匙匠核实键盘那条全对**：同拍成立 · 无 EX2000 · key14 真空闲 · `8'd12` 语义正确 · 判据⑪ 非空洞 · 三文件确未改 · 文档计数与 LF 都对
- ⭐ **待用户拍板**：**键 14 的"默认音高"要不要连 `base_semi`（八度/起始音）一起复位？**

### 5.6 🔴 全部修复完成后**唯一未关的门 = PnR**

```
⭐ 本轮所有 RTL 改动（23:03~23:06）都【晚于】最后一次综合（21:07）
⇒ EX2000 / 面积 / 时序 / 引脚【全部未验证】
⇒ ⭐ 必须重跑 sim/gowin_build.ps1，且【单独看综合日志有没有 ERROR】
   （⛔ 别只看 exit code —— 本项目有"仿真全绿、综合才炸"的前科）
```
