hokuu1102/Gowin2026-PolySynth/bringup/18-上板验证卡-功能修复-20260930深夜.md

# ⭐⭐ 上板验证卡 · 本版功能修复（2026-09-30 深夜）

> **要回答的唯一问题**：⭐ **本次修的这几处功能，到底修好了没有？**
>
> **本版**：`deliver` = `7a32935` ＋ ⭐ 顶层 `SEL_DRUM` 改为 **1（鼓机）**（2026-09-30 深夜 · 用户裁定）
> **现场条件（已确认）**：⭐ **两块左手板都在位** ✅
> **配套**：`bringup/16-上板操作手册-20260929.md`（接线 / 烧录 / 三条铁律 · 安全）
> ⚠️ **本卡取代** `files/20-代码/上板验证清单.md` §五 的第 **5**、**9** 两条 —— ⭐ 那两条本次已被修

---

## 🔴🔴 本卡的硬纪律：⭐ 每条判据都必须【能红】

```
⭐ 把【修复前】的 `.fs` 烧上去，这条判据必须给出【不同的】结果。
⛔ 不能红的"判据"不是判据 —— 它只是"看起来正常"。
```

📌 依据：全局 `0.11` 第 2 步「假设必须双向验证」＋ 经验库 `C83`（**探针假绿**：
唯一判据是「**跑未修复代码必须输出不同**」）。

⇒ ⭐ **本卡每条判据都写出 🔴 红长什么样**。**上板时先确认那个"红"是可分辨的**，
⛔ 不要只看绿色通过就收工。

---

## ⭐⭐⭐ 现象速查（⭐ **上板时先看这一节** —— 全是"看得见 / 听得见"的现象）

> ⭐ 本节只讲**感官现象**（⛔ 不出现寄存器、不出现 `'N'` 读数）。
> ⭐ 下面 §三 的 T1~T8 才是**机械判据**（⭐ 用来把现象钉死成可复现的判据）。

### 一、⭐ 上电正常时的【现象时间线】

| 时间 | ⭐ 你该听到 / 看到 |
|---|---|
| **0 s** | 上电 ⇒ 电源灯亮 · `CFG_LED`（`V13`）**绿灯 ~1 Hz 闪**（⭐ 唯一的活体见证） |
| **40 ms ~ 1.04 s** | ⭐ **自检和弦**：A4 + C#5 + E5 **同时响** ⇒ 约 **1 秒后自己停** ⇒ 之后**安静** |
| **≈0.2 ~ 1 s 之间** | 串口吐一个 **`T`** ⇒ ⭐ **这就是"可以开始弹了"的信号**（autotare 跑完） |
| **之后** | ⭐ **按第一下键就出声**（⛔ 不用先按十几个键）· 每个键发**它自己的音** · 按住 ⇒ 松开**正常衰减、不挂音** |
| **复位** | ⭐ **与上电完全一致**（等 ~1 秒、按第一下就出声）—— ⭐ **这就是"修A"的全部意义** |

⚠️ **从复位到串口出 `T` 之前，手别碰键**（⭐ 否则零点可能被记成"按下的位置"）。

### 二、⭐⭐ 修前现象 vs 修后现象（⭐ 一张表看完）

| # | 你听到 / 看到 | 🔴 修前（故障现象） | ✅ 修后 |
|---|---|---|---|
| **1** | **自检和弦** | 🔴 **"分解版"** —— 三个音**不是一个一个响**（16 轴全被判"按下"⇒ 事件洪泛） | ⭐ **三个音同时响**，1 秒后干净停下 |
| **2** | **第一下键** | 🔴 **要按十几个键才出声**（只有"碰巧捕获对零点"的轴能响） | ⭐ **第一下就出声** |
| **3** | **复位之后** | 🔴 **"复位一下就好了"**（复位**保留**了上次的零点，所以复位后正常、上电反而不正常） | ⭐ **复位 == 上电**，两者行为一致 |
| **4** | **某几个键** | 🔴 某个键**怎么按都不响**（零点被记成"按下位"⇒ `pos ≡ 0`） | ✅ 正常出声。⚠️ **但有个例外** ⇒ 见 §三 |
| **5** | **板2 的音量** | 🔴 ⭐ **"板2 比板1 小声"** —— 只按板1 跑 `'S'`，串口**照样回 `.`**（**假成功**），⭐ 而板2 那一路**根本没标上** | ⭐ 串口**回 `'1'`** ⇒ 板2 的失败**看得见**了 |
| **6** | **`'S'` 为什么失败** | 🔴 串口**只有一串 `!`** ⇒ 分不清"没按稳"还是"那片报 err"（⭐ 两者修法完全不同） | ⭐ 回**不同字母**：`w`=手在动 · `!`=没按稳 · `1`/`2`=哪一片报 err |
| **7** | **按对了还失败** | 🔴 某轴失败后，**明明按对了还回 `!`**（读到**上一轴**的残留 `err`）⇒ 要多试一两次才过 | ⭐ 纠正后**下一次直接过** |
| **8** | **上电瞬间发 `'S'`** | 🔴 **受理**（回 `s`）⇒ 但随后 autotare 会把**正在标的那个轴**的零点写坏 | ⭐ 回**一个孤零零的 `!`**（⭐ 不带 `s`、不带轴号） |
| **9** | **标定时手在动** | 🔴 零点被记成**晃动中的瞬时值** ⇒ 那几个键就坏了 | ⭐ **帧间在变就不捕获** ⇒ 标定期间碰键**不毁零点** |
| **10** | **`t` → `T` 的间隔** | 🔴 **快得看不出来（~0.5 ms）** —— ⭐ 溢出那一版"**一个 `tare` 都不发，却照样回 `T`**" | ⭐ **约 7 ms**（8 轴 × 2 ms） |
| **11** | **鼓机** | —（本版才有） | ⭐ **本版默认就是鼓机** ⇒ 发 `'B'` **开始打鼓**（从强拍起）· 发 `'D'` **换节奏型**（4 个）<br>⚠️ **不发 `'B'` 就一点声都没有**（源 B 上电静音）—— ⭐ **这不是坏的** |

### 三、⚠️ 两种**症状相反**的"某个键不正常"（⭐ 别记混）

```
🔴 修前：零点被记成【按下的位置】⇒ 松手后 pos ≈ 0
        ⇒ 现象 = ⭐ 那个键【怎么按都不响】（或只有一点点声）

⚠️ 修后（守卫【跳过】了那个轴）：zero_vld = 0 ⇒ 退回默认 ⇒ pos = 1023（≫ 触发阈 64）
        ⇒ 现象 = ⭐ 那个轴【永久判"按下"】⇒ 一直响 / 挂音

⇒ ⭐ 一句话区分：⭐ 串口发 'N' 读那一轴 —— 松手时 ≈ 0000 = 正常 ／ ≈ 1023 = 被跳过
```

### 四、⭐ `'S'`（span 标定）的现象流程

```
① 发 'X'                     ⇒ 回 'x'（⭐ 取消上一轮 —— 【每轮都必须先发】）
② 发 'S'                     ⇒ 回 's'（受理）⇒ 之后【逐轴】提示轴号
③ 按当前轴的键到底、【停住】1~2 秒
      · 成功 ⇒ 回 '.'，随后提示下一轴的轴号
      · 失败 ⇒ 回【拒绝字节】（'!' / 'w' / '1' / '2' …）⇒ 重试（每轴最多 8 次）
④ 16 轴走完                  ⇒ 回 'D'

⚠️ 'D' 是【粘滞】的 ⇒ ⭐ 第二轮【不会】再有 'D'（⛔ 别等它）⇒ 所以每轮先发 'X'
⚠️ 标定期间会听到"卡卡的重触发声" ⇒ ⭐ 正常现象，松手就停
⚠️ 标定时【两块板的同号键必须同时按到底】（⭐ K-127 不免除这一点）
⚠️ 标定完之后**手感会变**（一碰就触发 / 半按=满按）⇒ ⭐ 一次复位即恢复（⛔ 别当故障）
```

### 五、⛔ 本版【听不到 / 看不到】的东西（⭐ 别以为是坏的）

| 现象 | 原因 |
|---|---|
| ⭐ **节拍器不响** | 本版源 B = **鼓机**（`SEL_DRUM=1`）⇒ 节拍器被综合扫掉 |
| ⭐ **鼓机也不响** | ⭐ **源 B 上电静音**（`met_on_r` 复位 = 0）⇒ ⭐ **要发串口 `'B'`** |
| ✅ **G#3 / A#3（物理键 14/15）无声** | 🔴 **2026-10-01 更正：⭐ 已修** —— 修B（池判据改按**来源**选，`928c7ed`）＋ ⭐ **用户上板实测：键 14/15 出声** ⇒ ⚠️ 本行原写"未做"**已过时**（⭐ 见 `bringup/21:62` · `bringup/25:48` · `下一步任务清单-20261001.md:20`） |
| ⭐ 颤音/推子无效 | `RIGHT_ADC_ENABLE = 0` |
| ⭐ `Q` 诊断包不回 | `DPOS_DIAG = 0` |

---

## 〇、⭐ 本卡验的是这几处改动（⭐ 可逐条追溯）

| # | 改动 | 代码位置（⭐ 本工作树口径） | 引入 | 判据 |
|---|---|---|---|---|
| **A** | `calib` **水位闸**（位图 ＋ 读侧默认值） | `rtl/drivers/calib.sv:122-131` · 复位清除 `:350-355` · **`err` 不再写 `gain_r`** `:275-286` | `e1d36bf` | **T1 · T3** |
| **B** | `calib_autotare` **静止守卫** ＋ `WAIT_CLK` 溢出修正 | `rtl/w3a/calib_autotare.v`（`STILL_TOL` 由 `top.v:1616` 传入） | `e1d36bf` | **T0 · T6** |
| **C** | **K-127**：`raw` **按轴选片** | `rtl/top.v:1717`（`sp_raw_sel`）→ `:1861`（`.raw_i`） | `e1d36bf` | **T5** |
| **D** | **阶段3**：两片 `err`/`busy` 聚合 | `rtl/top.v:1477-1479`（`SPAN_CHECK_BOTH=1`）→ `:1866-1867` | `e1d36bf` | **T4** |
| **E** | **`at_done` 门控**（`'S'` 与 autotare 互锁） | `rtl/top.v:1602-1603` → `:1854` | `e1d36bf` | **T2** |
| **F** | **拒绝原因码**（6 个来源各一个字节） | `rtl/top.v:2023-2032` · `rtl/w3a/calib_span.v`（`rej_why_o`） | `e1d36bf` | **T7** |
| **G** | **`span_sent_r2`**：`err` 归属**本轴** | `rtl/w3a/calib_span.v:289` · 判据 `:586` | `e1d36bf` | **T8** |

⭐ **行号口径**：本卡所有 `top.v` 行号 = **当前工作树**（⭐ 因深夜 `SEL_DRUM` 改动，`120` 行之后比
`7a32935` **+6 行**）⇒ ⭐ **提交后即为文件内真实行号** ✅

---

## 一、⚠️ 前提（⛔ 缺一条，判据就无效）

### 1.1 🔴 串口必须走 **`J9` 排针**，⛔ **不是板载 USB-C**

⭐ **实测结论**（用户 2026-09-30 亲验 ＋ `constr/top.cst:331-357` 的记录）：

```
🔴 板载 USB-C 的串口【走不通】——
   BL616 跑的是 TangCore 游戏机固件，它的 UART 是【私有协议】（2 Mbps）
   ⇒ ⛔ 不透传我们的 T/S/X 命令（⭐ 实测：发任何字节都被"回显"）
⭐ 而原来的 V14/U15 【只在 J2 板对板连接器上】（0.4 mm 间距）⇒ 🔴 物理上插不了线
⇒ ✅ UART 已搬到 J9 排针（2.54 mm，杜邦线可插）：

      USB-TTL 的 TX   →  J9 的 N26   （ D14 = uart_rx ）
      USB-TTL 的 RX   →  J9 的 N25   （ D15 = uart_tx ）
      USB-TTL 的 GND  →  J9 的 GND

   ⭐ 500000 baud · 8N1 · ⛔ 无流控（BAUD_DIV=100 ⇒ 50 MHz ÷ 100 = 500 kbps 整除）
```

⭐ **驱动板子的工具**（⭐ **带时间戳** —— 本卡一半判据靠它）：

```powershell
python tools\board_probe.py <COM口> --send "N,N,N,N,N,N,N,N,N,N,N,N,N,N,N,N"
python tools\board_probe.py <COM口> --send S --follow S --follow-gap 0.02 --follow-count 60
python tools\board_probe.py <COM口> --listen 3
```

### 1.2 ⭐ 本版编译期开关（⭐ 实测值 —— 决定哪些判据【可达】）

| 开关 | 本版值 | ⚠️ 对验证的影响 |
|---|---|---|
| `SEL_DRUM` | **1**（鼓机） | ⭐ 源 B = **鼓机**（⛔ 节拍器被综合扫掉） |
| `METRONOME_ON` | **1** | 编译期总闸开 ⇒ 源 B 可用 |
| `met_on_r`（`top.v:467-470`） | **复位 = 0** | ⭐⭐ **源 B 上电【静音】** ⇒ ⛔ 鼓机不会自己响，⭐ **要发串口 `'B'`** |
| `DPOS_DIAG` | **0** | 🔴 `'Q'` 诊断包**关** ⇒ ⭐ `probe_q.py` 的 `Q` 包**验不了** |
| `SCORE_UART_ENABLE` | **1** | ⭐ 曲谱 ＋ looper **同时可用** |
| `RIGHT_ADC_ENABLE` | **0** | ⛔ 颤音类判据**上板不可达** |
| `VEL_AXIS_N` | **16** | ✅ 两块左手板都在位 ⇒ 轴 0~15 全可用 |
| `SPAN_CHECK_BOTH` | **1**（`top.v:1477`） | ⭐ 两片 `err` 都上报 ⇒ ⭐ **T4 要验的就是它** |

### 1.3 ⭐⭐ 操作铁律（⛔ 违反会得出错结论）

| # | 铁律 | 为什么 |
|---|---|---|
| **1** | ⭐ **每轮 `'S'` 之前必须先发 `'X'`** | `'S'` **只在 `S_IDLE` 被响应**（`calib_span.v:336-345`）⇒ 上一轮没结束时报 `s` 但**什么都不做** ⇒ 🔴 看着受理、实际不动（`X` 见 `:315-333`） |
| **2** | ⭐ **`'D'` 是粘滞的** ⇒ **第二轮不会再有 `D`** | `done_o` 粘滞 ⇒ `ev_done` 无上升沿。⭐ 脚本判据必须**每轮先 `'X'`**，⛔ 别等第二个 `D` |
| **3** | ⚠️ **`'0'`/`'1'`/`'2'` 与【轴号字符】同形** | ⭐ 按**位置**区分：**拒绝字节总是紧跟在【一个轴号之后】**（`top.v:2005`） |
| **4** | ⚠️ **跑完 `'S'` 之后的手感不可信** | 阈值仍按旧量纲（`EVT_TRIG_TH=64`，`top.v:2204`）⇒ `'S'` 后触发点从 8.6% 掉到 1.6%。⭐ **一次复位即恢复** |
| **5** | ⚠️ **`'S'` 期间听到"卡卡的重触发声"是正常的** | `cal_ch` 每 ~10 ms 切换 ⇒ `pos` 跳变 |

---

## 二、⭐⭐ 先做**这一个**测量：`t` → `T` 的时间差（**T0**）

> ⭐⭐ **为什么先做它**：它**一行判据同时覆盖三件事**，而且**能提前暴露 R1 那条致命风险**。

**依据**：`'t'` = 受理 tare（`top.v:2049`）· `'T'` = autotare 完成（`at_done` 上升沿，`top.v:2042`）
`WAIT_MS = 1000` · `STILL_FRAMES = 4` · 帧 500 µs ⇒ 每轴最快 **2 ms**，8 轴 ≈ **7 ms**；
`STILL_TOL = 8`（`top.v:1616`）· 超时 ⇒ 该轴**跳过**、8 轴全超时 ≈ **8 s**。

```powershell
python tools\board_probe.py <COM口> --send T        # ⭐ 看 t 与 T 的时间戳差
```

| 实测 | 判定 |
|---|---|
| ⭐ **≈ 7 ms** | ✅ **正确**（守卫在工作 ＋ `WAIT_CLK` 没溢出 ＋ `STILL_TOL` 够松） |
| 🔴 **≈ 0.3~0.5 ms** | 🔴 **修复前 / 溢出版** —— `WAIT_CLK` 回绕成负数（`WAIT_N=1`）⇒ **一个 `tare` 都不发，但照回 `T`**。`autotare` 无守卫时也是这个量级 |
| 🔴 **≈ 8 s** | 🔴 **全通道静默超时** ⇒ ⭐ 见 **R1**（`STILL_TOL=8` 对静止噪声太紧）⇒ 16 轴 `zero_vld=0` ⇒ **全体挂音** |

**🔴 红**：≈0.3~0.5 ms（溢出版）或 ≈8 s（守卫全超时）。⭐ 两种都**照回 `T`** ⇒
⛔ **只看到 `T` 绝不能判定"autotare 成功"**（这是本卡最重要的一条认知）。

⚠️ **补充判据（行为面）**：T0 之后连发 16 次 `'N'`：
🟢 松手静止 ≈ **`0000`**（16 轴全标上）｜🔴 全 ≈ **`1023`**（全被跳过 ⇒ 全体挂音）。

---

## 三、⭐ 判据 T1 ~ T8（⭐ 每条都能红）

### T1 · ⭐⭐ 水位闸 A：一次【失败的 `'S'`】不得毁掉已标定的归一化

**依据**
```
✅ 修复后：`calib.sv:275-286` —— `err` 分支【只置 err】，⛔ 不再写 `gain_r`
🔴 修复前：`e1d36bf^:rtl/drivers/calib.sv:202-204` ——
           if (raw_f <= zero_r[cal_ch]) begin
               err <= 1'b1;
               gain_r[cal_ch] <= (1 << 8);      // 🔴 归一化增益被清成 1.0
           end
           ⇒ 受害轴满按读数从 4095 掉回 ≈ 0744（旧量纲）
```

**操作**
1. 发 `'X'` ⇒ 双板同号键**同时按到底** ⇒ 发 `'S'` ⇒ 等到 `D`
2. 连发 16 次 `'N'`（**松手**）⇒ 再逐个**按到底**读一遍（**满按**）
3. 🔴 **故意制造一次失败**：⭐ **确定性造法**（见下）⇒ 再发 `'S'`
4. 第三次连发 16 次 `'N'` ＋ 再按到底

⭐ **确定性造法（`err` 判据是 `raw <= zero`，`calib.sv:275`，⛔ "只按板1"不保证）**：

```
⭐ 按住【板2】某个键、【静止不动】⇒ 发 'T' ⇒ 等 T ⇒ 松手 ⇒ 发 'X' ⇒ 再发 'S'
   📌 为什么必然 err：⭐ tare 脉冲【两片广播】、而每片的 calib 各读【自己的 raw】
      ⇒ 片1 的 zero[该ch] 被记成"按下位" ⇒ 松手后 raw < zero ⇒ 必 err
   ⚠️ 而静止守卫【只看片0】（`top.v:1628`）⇒ 按板2 不触发守卫 ⇒ tare 照常发出
```

**🟢 绿**：步2 松手 ≈ **`0000`**、满按 ≈ **`4095`**；步3 回**拒绝码**；
⭐ 步4 满按 **仍 ≈ `4095`**。
**🔴 红**：步4 满按**掉到 ≈ `0744`** ⇒ `gain_r` 被清 = **修前形态**。

⚠️ `MAX_TRAVEL = 1023`（`calib.sv:38`）是**静默上界**：⭐ 某轴 raw 行程 > 1023 时
`pos` **永远到不了 4095**（被夹住且不报错）⇒ ⭐ 先读 `'P'` 确认行程再解读。

---

### T2 · ⭐ `at_done` 门控：上电/复位后的 **200 ms 窗口**内 `'S'` 必被拒

**依据**
```
✅ 修复后：`top.v:1602` sp_start_gated    = cmd_span_req &  at_done
           `top.v:1603` sp_start_rejected = cmd_span_req & ~at_done
🔴 修复前：`e1d36bf^:rtl/top.v:1538`      = cmd_span_req & ~at_busy
           ⚠️ at_busy 只在 ST_SWEEP 高 ⇒ 上电 ST_WAIT 那 200 ms 内【不拒】
回包     ：`top.v:2041` sp_start_rejected ⇒ '!'（⭐ 优先级【高于】cmd_span_req `:2044` ⇒
           ⭐ 被拒时【只有一个孤零零的 '!'】—— 连 `s`、连轴号都没有）
时间常数 ：DELAY_CLK = 10_000_000 @50 MHz = 200 ms（ST_WAIT）⇒ at_done 最早 ≈216 ms 上升
```

**操作（⭐ 免计时法：用 `T` 当标记，⛔ 不用掐表）**

```powershell
# ⭐ 上电（或按板载复位键 AA13）的【同时】跑这条，抓 1.2 秒
python tools\board_probe.py <COM口> --send S --follow S --follow-gap 0.02 --follow-count 60
```

**🟢 绿**：`! ! ! … !` **`T`** `s` …（⭐ `T` 之前**全是** `!`，且每个 `!` **后面没有轴号**）
**🔴 红**：⭐ **第一个回包就是 `s`**（`T` 之前没有 `!`）⇒ 门控没生效

⛔ **⚠️ 关键（⭐ 别在这里下错结论）**：分歧窗口**只有上电/复位后的 0~200 ms**。
⭐ 在 500 ms（自检和弦还在响时）发 `'S'`，**两版都受理 ⇒ 不区分**。

---

### T3 · ⭐ 水位闸 B：**复位后 `'N'` 应为"未标定"态**

**🔴 先说一条关键更正（⭐ 我第一次差点给错判据）**

```
⛔ 真·冷【上电】时的 `'N'` 读数，修复前后【逐位相同】！
   因为：数组上电值 = 0 / 256 / 0，而水位闸的"读侧默认值"就等于这些上电值
   ⇒ ⭐ 水位闸对【真·冷上电】零改变 ⇒ ⛔ 拿它当判据 = 假绿
✅ 真正的差异在【逻辑复位】：🔴 修前【沿用】复位前的旧 zero_r/gain_r（读数看着正常）
                          ⇒ ✅ 修后位图清零 ⇒ 退回默认 ⇒ 'N' ≈ 1023
```

**操作**：复位前先正常标定过一轮 ⇒ 按板载复位键 `AA13` ⇒ ⭐ 复位后**立刻**连发 `'N'`（在 `T` 之前）

**🟢 绿**：复位后（`T` 之前）`'N'` ≈ **`1023`**；出 `T` 之后回到 **`0000`**
**🔴 红**：复位后 `'N'` **立刻 ≈ `0000`** ⇒ 沿用了旧 `zero_r` = **修前形态**

---

### T4 · ⭐ 阶段3：**片 1 的标定失败必须可见**

**依据**：`top.v:1477-1479`（`SPAN_CHECK_BOTH=1` ⇒ `cal_err_any = cal0_err|cal1_err`
⇒ `:1867 .cal_err_i`）；
`top.v:2023-2027`（拒绝字节 `'0'`/`'1'`/`'2'` = 片0/片1/两片 err）。
🔴 修复前 `calib_span` 只拿到**片0** 的 `err`/`busy`（旧 `:1774-1775`）⇒ 片1 失败**静默** ⇒ 一路 `.` 到 `D`。

**操作**：⭐ **只按板 1**（板 2 同号键不动）⇒ 发 `'S'`

| | 观察 |
|---|---|
| **🟢 绿** | 回 **`'1'`**（片1 err）或 **`'2'`**（两片）—— ⭐ **不可能一路 `.` 到 `D`** |
| **🔴 红** | ⭐ **一路回 `.`，最后 `D`**（看着"成功"）⇒ 片1 失败被吞 = **修前形态** |

⚠️ **"只按板1"不保证每次 `err`**（判据是 `raw <= zero`，松手位 ≈ 零点）⇒
⭐ 要**确定性**看到 `'1'` ⇒ 用 **T1 的"按住板2 静止发 `'T'`"造法**。
📌 只接**一块**板时：片1 `miso` 悬空上拉 ⇒ raw 恒 4095 ⇒ **恒 `err`** ⇒ `'S'` **永远回 `'1'`**
（⛔ 永不通过；要它能通过得把 `top.v:1477` 的 `SPAN_CHECK_BOTH` 改 `0` **重编译**）。

---

### T5 · ⭐ K-127：`raw` **按轴选片**（⭐ 激励—响应，⛔ 不依赖噪声阈值）

**依据**：`top.v:1717` `sp_raw_sel = sp_cur_axis[3] ? af1_pol : af0_pol`
（bit3 = 片号：轴 0~7→片0、8~15→片1）→ `:1861 .raw_i (sp_raw_sel)`。
🔴 修复前恒接 `af0_pol` ⇒ **标定轴 8~15 时读的是片0 的码**。

🔴🔴 **`'P'` 不但看不到这件事 —— 它还会【误导你】**（⭐ `D11` / `BATCH 8.1`，⭐ 2026-09-30 夜**自查确认**）
依据：`top.v:1737 .pos_i (af0_pol)` **硬接片0** ＋ `pos_probe.v:91/97`
—— ⭐ **模块只有【一路】`pos_i`（12 位）与一个 `ch_i`（4 位），⭐ 根本没有"片"这个维度**
⇒ ⭐ `'P'` **永远只回片 0 的值**：
   · ⚠️ **按板 2 的键发 `'P'` ⇒ 看到的是【板 1 同号键（静止）】的码**
     ⇒ 🔴 **会得出"按键没反应"的错误结论**（⭐ 比"看不到"更危险）
   · ⛔ **所以：⭐ 板 2 的键【别用 `'P'` 判断】**
   · ✅ 能用的是 **`'S'` 的回包**（⭐ 原因码）与 **`'N'`**
     （⭐ `'N'` 已修：按 **16 轴轮转**，⭐ 见 `top.v:2350-2362`；⭐ `'Q'` 也是全 16 轴 `:2407-2415`；
     ⚠️ ⭐ **三个探针里只有 `'P'` 没修**）

**操作**：标定**轴 8**（片1 的 ch0）时：

| 你做什么 | 🟢 绿（修后） | 🔴 红（修前） |
|---|---|---|
| ⭐ **故意抖片1 的轴 8** | 回包**跟着变**（`w` 离散度 / `!` 超时） | ⭐ **完全无视片1** ⇒ 回包**不随它变** |
| ⭐ **反向对照：抖片0 的 ch0** | 回包**不变** | 回包**跟着变** |

⇒ ⭐ **一句话判据**：**回包跟"片1"动、不跟"片0"动** = 绿；**反过来** = 红。

---

### T6 · ⭐ 静止守卫（⭐ 关键：它的失败是【纯静默】的）

**它实际签的契约**（依据 `rtl/w3a/calib_autotare.v`）
```
· 比什么：⭐【逐通道】帧间差 |sample_data_i − last_raw[ch]| ≤ STILL_TOL(8)，连续 STILL_FRAMES(4) 帧才 tare
· ⚠️ 只看【片0】（`top.v:1628 .sample_data_i (af_data[0*12 +: 12])`）
· 超时 1000 ms ⇒ 该通道**跳过**（不发 tare）、进下一通道 ⇒ 8 通道全超时 ≈ 8 s
```

## 🔴🔴 它的失败【一个码都不回】（⭐ 本节最重要的一条）

```
⭐ `at_skip` / `at_fail`（`top.v:1586-1587`，接到 `:1638-1639`）在 `rtl/` 内【没有任何读点】：
   既无 UART、也无 LED；⭐ 而且扫完照样进 ST_DONE ⇒ 【照样回 `T`】—— 与成功【同形】！
```

⭐ **唯一可观测的间接判据**：被跳过的轴 `zero_vld = 0` ⇒ 读侧退回默认
⇒ ⭐ 松手时 `'N'` = **`1023`**（⛔ 不是 0）。
📌 而 `'P'` **看不出**（它回的是**原始码** ≈2110，不经过水位闸）。

**操作 E1**：不晃，发 `'T'` ⇒ 🟢 `t→T ≈ 7 ms`、16×`'N'` 全 ≈ `0000`
**操作 E2**：⭐ **按住板1 某键【晃动】** ⇒ 发 `'T'`
  🟢 绿（修后）：`t→T ≈ 8 s`（该轴超时被跳过）＋ ⭐ 该轴 `'N'` = **`1023`**
  🔴 红（修前）：`T` 在 **≈0.5 ms** 就回，且⭐ **零点被记成晃动中的瞬时值**
**操作 E3（验它的【盲区】）**：⭐ **只晃板2（片1）** ⇒ 🟢/🔴 两版**都 ≈7 ms**
  ⇒ ⭐ 证明"守卫只看片0"⇒ ⚠️ **片0 抖/坏会连坐两片该通道**（⭐ 这是已知缺口，⛔ 别当回归）

⚠️ **能力边界（⛔ 别高估）**：它只判"**动没动**"，⛔ **不判"是不是松手位"**
⇒ ⭐ **一直按住不动 ⇒ 照样把按下位记成零点**；片拔掉（MISO 恒 4095）是静止的 ⇒ 照样记 4095。
⚠️ `calib_autotare.v:53-56` 的注释把这两种写成"它要解决的问题" ⇒ 🔴 **与代码实际能力不符**。

---

### T7 · ⭐ 拒绝原因码（⭐ 原始映射 ＋ 哪些**上板造不出**）

**依据 `top.v:2023-2032`**（⭐ 代码里的原表，⛔ 不是二手转述）：

| 字节 | 含义 | 上板能不能**刻意**造出来 |
|---|---|---|
| **`!`** `0x21` | **R1 稳定判据超时**（`S_SETTLE` 1 s 没凑够 8 帧静止） | ✅ 发 `'S'` 后**持续晃动**该轴 >1 s ⇒ 每 1 s 一个 |
| **`!`** `0x21` | ⭐ **第 7 个来源**（⭐ 文档只记 6 个）：`'S'` 被 `at_done` 门控拒 | ✅ 上电 <200 ms 内发 `'S'`（→ T2）。⚠️ **只有孤零零一个 `!`** ⇒ 靠**位置**区分 |
| **`o`** `0x6F` | R2 投票收帧超时 | 🔴 **造不出** —— `adc_farm` 恒产 `sample_valid`（`drivers/adc_farm.sv:16 · :156`）⇒ 帧流不停 |
| **`w`** `0x77` | R3 投票 8 帧 `max−min > VOTE_TOL(96)` | ✅ **慢推/匀速滑**该轴：帧间差<48（settle 过）但 8 帧累计>96。⚠️ **快抖 ⇒ 变成 `!`** |
| **`b`** `0x62` | R4 等帧超时 | 🔴 **造不出**（同 `o`） |
| **`?`** `0x3F` | R6 `span` 已发 1 s，**既无 busy 也无 err** | 🔴 **几乎造不出** —— 真 calib 里 `err=0` 必伴随 `busy=1`（`calib.sv:275-288` 是 if/else）⇒ 只有**连线/网表坏**才出现 |
| **`0`/`1`/`2`** | R5 `span` 已发 ＋ 片0/片1/两片 `err` | ✅ 见 T1 的确定性造法（按住板2 静止发 `'T'`）⇒ **必然** `1` |
| **`.`** `0x2E` | 本轴通过 | — |
| **`D`** `0x44` | ⚠️ 全部完成 —— 🔴 **放弃也是 `D`** | ⭐ 靠**数 16 个轴号与 `.` 的个数**判断，⛔ 别只看 `D` |
| **`s`**/`t`/`x` | 受理 span / tare / 取消（`top.v:2049-2052`） | — |
| **`T`** `0x54` | ⭐ autotare 完成（`at_done` 上升沿） | — |

⚠️ **两个与交接文档不符的地方（⭐ 以代码为准）**
1. 🔴 交接文档写"**不接左手板 ⇒ 回 `?`**" ⇒ ⭐ **按代码应是 `1`**（断片 ⇒ raw ≤ zero ⇒ err）。
   ⇒ ⭐ **真看到 `?` 请按【接线/网表故障】查，⛔ 别去查霍尔**。
2. 🔴 `top.v:2021` 那个 `?`（`cal_err_chip == 2'b00` 兜底）是**死分支**
   （`cal_err_any = cal0_err|cal1_err` ⇒ 片号不可能全 0）⇒ ⛔ **不可达，别写进判据**。

**操作**：
```powershell
python tools\board_probe.py <COM口> --send S --follow V --follow-gap 0.05 --follow-count 40
python tools\board_probe.py <COM口> --send S --follow V --follow-gap 0.05 --follow-count 20 --repeat 5
```

| | 观察 |
|---|---|
| **🟢 绿** | ⭐ 拒绝**带得出**具体原因字节（出现 `w` / `1` / `2` 等）＋ ⭐ 时间戳能分开"超时"(≈1000 ms)与"离散度"(≈8 ms) |
| **🔴 红** | 🔴 **所有拒绝一律是 `!`** —— ⭐ 因为修复前 **`rej_why_o` 根本不存在**（`git log -S` 只命中 `e1d36bf`）⇒ 6 条出边完全分不出 |

⚠️ `rej_why_o` **不经过 `'V'`** —— `'V'` 仍只有 `state`/`axis`/`rej`（**7 字节**，
`V<state><axis><rej><'0'>`）。⚠️ `span_probe.v:33` 注释写"9 字节 `…<rej2>`" ⇒
🔴 **注释错、代码对**（`rej2` 恒 `'0'`）。

---

### T8 · ⭐ `span_sent_r2`：`err` 必须归属**本轴**（⛔ 不是上一轴的残值）

**依据**：`calib` 的 `err` 是**寄存器**，收到 span 的**下一拍**才更新且**跨轴保持**
⇒ `S_NEXT` 第一拍读到的是**上一轴**的 `err`。
⭐ 修法：`span_sent_r2 <= span_sent_r`（`calib_span.v:289`），R5 判据改用 `span_sent_r2`（`:586`）。
🔴 而 R5 **排在 `busy` 之前** ⇒ **修前只要有残留 `err` 就必定假拒绝**。

**操作（利用"拒绝后重试的是同一个轴"这个结构）**
1. 先让某轴**真失败一次**（+速度/中途松手 ⇒ `raw <= zero`）⇒ 看到 `1`
2. ⭐ **立刻纠正**（两片该键按到底**保持住**）
3. 看下次尝试的回包

| | 观察 |
|---|---|
| **🟢 绿（修后）** | 纠正后**直接 `.`** |
| **🔴 红（修前）** | ⭐ **还会再回一个 `1`**（读到残留 `err`），**第三次**才 `.` |

⇒ ⭐ **判据 = "失败 → 纠正 → 通过"之间多出的拒绝次数：修后 `0`、修前 `1`。**
⚠️ 拒绝字节总紧跟在轴号之后 ⇒ ⭐ `1` 与轴号 `1` 同形，**按位置数**。

---

## 四、🔴🔴 风险 **R1**：`STILL_TOL = 8` 可能让**整块板**不能用（⭐ 现场第一个测量就能暴露）

```
⭐ `calib_autotare` 的静止判据 = 帧间差 ≤ 8 码（`top.v:1616` 传入）
⚠️ 而 `span` 侧因为实测"按住时 Δ≈23" 已把 `SPAN_STABLE_TOL` 从 8 提到 **48**（`top.v:258-259`）
🔴 但 `autotare` 这一侧【仍然是 8】
⇒ ⚠️ 若静止噪声 > 8 ⇒ 全通道 1 s 超时 ⇒ ≈8 s 后照回 `T`
   ⇒ ⭐ 16 轴 zero_vld 全 0 ⇒ 松手 pos 全 = 1023（≫ EVT_TRIG_TH=64）
   ⇒ 🔴 **16 轴全部永久判"按下" ⇒ 全体挂音**
```

⭐ **现场一测即知**：`t → T` 是 **~7 ms**（✅）还是 **~8 s**（🔴 ⇒ 命中 R1）。
⚠️ 命中时**别去查霍尔/接线** —— ⭐ 那是**参数**问题（把 `STILL_TOL` 放宽，与 `span` 侧对齐）。
📌 依据：`files/00-总览/交付线-20260930.md` §九② 已给出同族加固建议（量程合理性 `raw ∈ [1000,3000]`）。

---

## 五、⛔ 本卡【不能】验证什么（⭐ 别硬造判据）

| # | ⛔ 不能验 | 为什么 |
|---|---|---|
| **1** | 🔴 **`'Q'` 诊断包 / `probe_q.py` 的 dpos 峰值** | `DPOS_DIAG = 0` ⇒ 要它得改 **1** 并**重跑 PnR** |
| **2** | 🔴 **颤音 / LFO** | `RIGHT_ADC_ENABLE = 0` ⇒ `vibrato_mod ≡ 0` |
| **3** | 🔴 **`o` / `b` 两个拒绝码** | ⭐ **上板造不出**（`adc_farm` 恒产帧） |
| **4** | 🔴 **`?` 拒绝码** | ⭐ **几乎造不出**（`err=0` 必伴随 `busy=1`） |
| **5** | ⚠️ **`pp_busy`/`np_busy`/`vp_busy`** | 被驱动但**无人读取** ⇒ 综合裁掉，**不构成观测手段** |
| **6** | ⚠️ **looper 录满/溢出** | 观测口**没接上板** ⇒ 只会**静默丢** |
| **7** | ⛔ **功耗 / 发热** | STA 不涉及 |

---

## 六、⚠️ 已知的、⛔ **不是本次回归**（⭐ 先别当故障）

| # | 现象 | 为什么 |
|---|---|---|
| **1** | 🔴 **G#3 / A#3（物理键 14/15）无声** | ⭐ **修 B（池判据重做）未做** ⇒ 保留池 `env_level` 被整段换成 `perc_level`，而 `perc_trig` 只在**上升沿**重装 ⇒ class-2 抢占时恒 0 |
| **2** | ⚠️ **跑完 `'S'` 后手感变了**（一碰就触发 / 半按=满按） | ⭐ 阈值仍按旧量纲；`'S'` 后 `pos` 量纲 0~4095 ⇒ 触发点 8.6% → 1.6%。⭐ **一次复位即恢复** |
| **3** | ⚠️ **`'S'` 期间"卡卡的重触发声"** | `cal_ch` 每 ~10 ms 切换 ⇒ `pos` 跳变 ⇒ **正常**，松手就停 |
| **4** | ⚠️ **发串口命令会让 `evt_uart_rx` 错误计数涨** | ⭐ 正常 |
| **5** | ⚠️ **鼓机要发 `'B'` 才响** | 源 B 被运行时 `met_on_r` 串住（复位 = 关）⇒ ⭐ 不是 bug |
| **6** | 🔴 **第二轮 `'S'` 没有 `D`** | ⭐ `done_o` 粘滞 ⇒ ⛔ **不是故障**，⭐ 每轮先发 `'X'` |

---

## 七、⭐ 记录表（⭐ 每测一项就填，⛔ 别凭记忆）

| ✅ | 项 | 判据 | 实测 | 判定 |
|---|---|---|---|---|
| ☐ | `.fs` 时间戳 / sha256 | 比构建时刻新 | | |
| ☐ | PnR 时序 | `0 setup / 0 hold` **且** `Fmax ≥ 51.5 MHz` | | <br>⚠️ **2026-10-01 更正**：⭐ 门槛已由 **5% 降到 3%**（⭐ 用户裁定）⇒ 判据改为 **`Fmax ≥ 51.5 MHz`**。<br>⭐ 理由：⭐ 5% 的原始依据已被用户撤回（⭐ 那次 0.18% 上板异常是**代码 bug**，⛔ 非时序问题）；<br>⭐ 当前实测 `52.372 MHz`（+4.744%）⭐ 在 3% 下通过。⚠️ **新增 UART 后必须重测并对比**。 |
| ☐ | **T0** `t`→`T` | 🟢 ≈7 ms ／ 🔴 ≈0.5 ms 或 ≈8 s | | |
| ☐ | **T0b** `T` 后 16×`'N'`（松手） | 🟢 全 `0000` ／ 🔴 全 `1023` | | |
| ☐ | **T1** 失败 `'S'` 后满按 | 🟢 仍 `4095` ／ 🔴 掉 `0744` | | |
| ☐ | **T2** 上电/复位 200 ms 内 `'S'` | 🟢 `!`…`T`…`s` ／ 🔴 开头就 `s` | | |
| ☐ | **T3** 复位后 `'N'`（`T` 前） | 🟢 `1023` ／ 🔴 `0000` | | |
| ☐ | **T4** 只按板1 跑 `'S'` | 🟢 `1`/`2` ／ 🔴 一路 `.` 到 `D` | | |
| ☐ | **T5** 抖片1 / 抖片0 | 🟢 跟片1 动 ／ 🔴 跟片0 动 | | |
| ☐ | **T6** E2 按住板1晃动 | 🟢 `t→T≈8 s` 且该轴 `1023` ／ 🔴 `T≈0.5 ms` | | |
| ☐ | **T6** E3 只晃板2（盲区） | ⚠️ 两版都 ≈7 ms（**预期如此**） | | |
| ☐ | **T7** 拒绝码是否丰富 | 🟢 有 `w`/`1`/`2` ／ 🔴 一律 `!` | | |
| ☐ | **T8** 失败→纠正→通过 | 🟢 直接 `.` ／ 🔴 多一个 `1` | | |
| ☐ | 声音：冷启动后**第一下**就出声 | 🟢 立刻出声 ／ 🔴 先"自检和弦"/要按十几个键 | | |
| ☐ | 声音：16 键逐个 | 🟢 各自出声（⚠️ 键 14/15 已知无声） | | |
| ☐ | 声音：按住⇒松开 | 🟢 正常衰减、不挂音 | | |
| ☐ | 鼓机：发 `'B'` | 🟢 响、从强拍起 ／ ⛔ 不发 `'B'` 就**不该响** | | |
| ☐ | 鼓机：发 `'D'` ×4 | 🟢 4 个节奏型可辨（BASIC/HOUSE/ROCK/DANCE_FILL） | | |

---

## 附 · ⭐ 证据来源（⭐ 全部核到代码，⛔ 无转述）

| 内容 | 来源 |
|---|---|
| 水位闸读写口 / 复位清除 / `err` 不写 `gain_r` | `rtl/drivers/calib.sv:122-131` · `:275-286` · `:350-355` |
| 修复前形态（`calib` / `top` / `autotare`） | `git show e1d36bf^:<路径>`（`calib.sv:202-204 · :252-272`；`top.v:1538`；`calib_autotare.v` 188 行版） |
| K-127 选片 | `rtl/top.v:1717` · `:1861` |
| 阶段3 聚合 | `rtl/top.v:1477-1479` · `:1866-1867` |
| `at_done` 门控 | `rtl/top.v:1602-1603` · `:1854` · `:2041` |
| 拒绝码原表 / 仲裁优先级 | `rtl/top.v:2023-2032` · `:2034-2052` |
| 静止守卫参数与静默跳过 | `rtl/top.v:1616` · `:1628` · `:1586-1587` · `:1638-1639` |
| `span_sent_r2` | `rtl/w3a/calib_span.v:289` · `:586` |
| `'S'` 只在 `S_IDLE` 生效 / `X` | `rtl/w3a/calib_span.v:336-345` · `:315-333` |
| `met_on_r` 复位 = 关 · `'B'` 开关 | `rtl/top.v:456-470` · `:3246-3248` |
| 打击包络一shot（`K-144`） | `rtl/top.v:3576-3619` |
| UART 在 `J9` 排针 | `constr/top.cst:331-367` |
| `adc_farm` 恒产帧（`o`/`b` 不可造） | `rtl/drivers/adc_farm.sv:16` · `:156` |
| autotare 时序 | `rtl/w3a/calib_autotare.v:50` · `:170-171` · `:215` |
| 静止守卫的能力边界 / 加固建议 | `files/00-总览/交付线-20260930.md` §九② |
| 修A 的根因链 | `files/00-总览/交付线-20260930.md` §四①②③ |
