hokuu1102/Gowin2026-PolySynth/bringup/19-标定操作流程-20261001.md

# 🎹 标定操作流程（⭐ `'S'` span 标定）—— 单音逐轴

> **用户裁定（2026-10-01）**：⭐ `B4` = **「可以，单音标定记录一下吧」** ✅
> ⇒ ⭐ **按"一次标一个音（一根轴）"的流程执行**，⭐ **并把流程记录在案** ✅
> **来源**：⭐ 章程 §九① ＋ ⭐ `cal_ch_mux` 的共享事实（⭐ 见下 §二）

---

## 一、⭐ 前置（⭐ 缺一不可）

| ⭐ # | ⭐ 项 | ⭐ 判据 |
|---|---|---|
| **1** | ⭐ 串口接 **`J9` 排针**（⛔ 不是板载 USB-C） | ⭐ `uart_rx = D14` · `uart_tx = D15` · **500000 8N1** ✅ |
| **2** | ⭐ 终端**能看到回包** | ⭐ 发 `'T'` ⇒ ⭐ **回 `T`**（⭐ 这证明收也通、发也通 ✅） |
| **3** | ⭐ **两块板都接好、⭐ 都上电** | ⚠️ 见 §二 —— ⭐ **标定需要两块板同时按** ✅ |
| **4** | ⭐ 磁轴**已稳定**（⭐ 上电后等 ~1 s） | ⭐ `calib_autotare` 的 `DELAY_CLK` 已过 ⇒ ⭐ `T` 能回 ✅ |

⚠️ **⛔ 不要在标定过程中动板子/换轴** —— ⭐ 会打断"连续静止"判定 ✅

---

## 二、⭐⭐ 关键约束：**两块板必须【同号键同时按】**

⭐ **这是硬件结构决定的，⛔ 不是软件 bug**：

```
⭐ cal_ch_mux = sp_busy_r ? sp_ch : at_ch      （⭐ top.v，⭐ 两片【共用同一个 ch】）
⭐ calib_span 的 span_o = {N_ADC{1'b1}}        （⭐ 两片【同拍广播】）
⇒ 🔴 若只按板 2 的同号键、⭐ 板 1 那个键没按
   ⇒ ⭐ 板 1 的 raw 仍是"松手值" ⇒ ⭐ calib 判 err=1
   ⇒ ⭐ top.v 的 cal_err_any 置起 ⇒ 🔴【整轴被拒】（⭐ RJ_CAL_ERR）✅
```

⇒ ⭐ **操作要求**：⭐ **对每一根轴，⭐ 同时按住【两块板上同一个键号】的键到底** ✅
⭐ **用户已确认可以做到** ✅（⭐ 一个人两只手即可 ✅）

---

## 三、⭐ 逐轴流程（⭐ 一次一根轴）

⭐ **对轴 `k = 0,1,2,…,15` 重复**：

| ⭐ 步 | ⭐ 动作 | ⭐ 期望回包 | ⚠️ 不对时 |
|---|---|---|---|
| **1** | ⭐ 发 **`'S'`** | ⭐ 回 **`s`**（受理） | ⚠️ 只回 `!` ⇒ ⭐ 看原因码 |
| **2** | ⭐ 看是否回 **轴号**（⭐ 如 `0`） | ⭐ 回 `0`~`9`/`A`~`F` | ⚠️ 不回 ⇒ ⭐ 见 §五 |
| **3** | ⭐ **两块板同时把轴 `k` 的键按到底**，⭐ **保持不动** | ⭐ 稳定后回 **`.`**（完成） | ⚠️ 回 `!` ⇒ ⭐ 该轴被拒（⭐ 见 §五） |
| **4** | ⭐ **松手** | ⭐ 自动进入下一根轴（⭐ 回下一个轴号） | — |
| **5** | ⭐ 重复到 16 根轴走完 | ⭐ 最后回 **`D`**（⭐ 全部完成 ✅）<br>🔴 **2026-10-01 更正**：原写"回 `T`" ⇒ ⚠️ **错**，⭐ 代码是 **`'D'`**（`rtl/top.v:2152`；⭐ 另见 `bringup/18:80`）<br>⚠️ 且 **`'D'` 是粘滞的** ⇒ 第二轮不会再出现（`bringup/18:163`） | — |

⭐ **回包样例**（⭐ 今晚 `tb_span_axis_over_uart` 实测复现过 ✅）：
```
s 0 . 0 . 0 ! 0 ! ... T
│ │ │ │
│ │ │ └─ ⭐ '.' = 该轴标定完成
│ │ └─── ⭐ '!' = 该轴被拒（⭐ 需重试）
│ └───── ⭐ 轴号（⭐ 十六进制：0~9 A~F）
└─────── ⭐ 's' = 'S' 受理
```

⚠️ **`!` 是【可重试】的** —— ⭐ 重标同一根轴**不算失败** ✅（⭐ `REJECT_MAX=8` 才放弃 ✅）

---

## 四、⭐ 判据（⭐ 什么算"标定成功"）

| ⭐ 判据 | ⭐ 值 |
|---|---|
| ⭐ **16 根轴全部收到 `.`** | ⭐ 完成 ✅ |
| ⭐ 最后回 **`T`** | ⭐ `at_done` 置起 ✅ |
| ⭐ **回包里有轴号** | ⭐ 证明"轴号真的发出去了"（⭐ `K-132` 已修 ✅） |
| ⭐ **`'!'` 的次数** | ⭐ 越少越好；⭐ 偶尔 `!` 后重试成功 = 正常 ✅ |

⚠️ **⛔ 别在 `'S'` 之前就弹琴** —— ⭐ 见 §五-① ✅

---

## 五、⚠️ 已知坑（⭐ 遇到对照）

| ⭐ # | ⭐ 现象 | ⭐ 原因 / 处理 |
|---|---|---|
| **①** | ⭐ **弹琴很硬**（⭐ 要按很深才出声） | ⚠️ **跑 `'S'` 之前**：⭐ `pos ∈ 0..1023`，⭐ 而 `TRIG_TH = 205` ⇒ ⭐ **需 20% 行程** ⚠️<br>⇒ ⭐ **先跑 `'S'`**（⭐ 之后 `pos ∈ 0..4095` ⇒ ⭐ 205 = **5%**，⭐ 手感正常 ✅）<br>📌 这是 `T-7` 方案的**固有代价**（⭐ 已写进 `top.v` 的注释 ✅） |
| **②** | ⭐ 只回 `!`，⭐ **没有轴号** | ⚠️ 查 `uart_tx` 那路（⭐ `D15`）＋ ⭐ 波特率（⭐ 500000 ✅） |
| **③** | ⭐ 某轴反复 `!` | ⚠️ **大概率是"两块板没同时按"** ⇒ ⭐ 重来，⭐ 按到底再保持 ✅ |
| **④** | ⭐ 按了没反应、⭐ 但 `'T'` 能回 | ⚠️ 查该轴**是否接好**（⭐ 磁轴 → `ADC` 通道 ✅） |
| **⑤** | ⭐ **全体挂音**（⭐ 每个音都不消失） | ⚠️ **`STILL_TOL` 相关** ⇒ ⭐ 已从 8 提到 **48** ✅（⭐ 见 `top.v:1616`）<br>⚠️ 若仍出现 ⇒ 🔴 **报我**，⭐ 要查"raw 抖动本身是否异常" ⛔ 不是继续加容差 ✅ |

---

## 六、⭐ 记录表（⭐ 你标定时填）

| ⭐ 轴 | ⭐ 键号 | ⭐ 结果 | ⭐ `!` 次数 | ⭐ 备注 |
|---|---|---|---|---|
| 0 | | | | |
| 1 | | | | |
| … | | | | |
| 15 | | | | |

⭐ **全 16 轴完成** ⇒ ⭐ 记一行 **"`'S'` 全通，⭐ `T` 收到"** ✅
⚠️ **若有轴始终 `!`** ⇒ ⭐ **记下轴号** ⇒ ⭐ 那是**要查的缺陷**（⭐ 不是"操作问题"就一定要报 ✅）
