hokuu1102/Gowin2026-PolySynth/bringup/24-上板卡-BA-T2起始音-20261001.md

# 🎹 上板卡 · **BA**（T2 起始音）· 2026-10-01

> ⭐ **要回答的唯一问题**：⭐ **发一个串口帧，键盘能不能【整体】升/降八度？**
> **前几版**：⭐ `AV`（量纲）· `AW`（音量）· `AX`（键盘打鼓）· `AZ`（鼓音高）—— ⭐ **它们的卡全部仍适用** ✅
> ⭐ **本版 = AZ ＋ T2**（⭐ 只多了"起始音八度移位" ✅）⇒ ⭐ **前面验过的都应当【仍然好】** ✅

> 🔴 **2026-10-01 深夜更正（⭐ `K-170` / `K-171`）**：⭐ 本卡里的 `58.347 MHz` 是在**错误器件**（`AC2/I1` = 基石板速度级）上测的 ⇒ ⭐ **对实物无效** ⚠️；⭐ 器件改对（`AC1/I0`）后**同一份逻辑**实测 ⭐ **`Fmax = 50.137 MHz`（⭐ 余量只剩 `+0.27%`）** ⚠️ ⇒ ⭐ **烧录本身不受影响**（⭐ 同 die 同封装，⭐ 之前一直能烧 ✅），⚠️ **但"余量 16.69%"这个结论作废** ✅

---

## 〇、烧哪个

| ⭐ | ⭐ 项 | ⭐ 值 |
|---|---|---|
| **文件** | ⭐ **`C:\Users\hokuu\Desktop\FPGA\FPGA2026\build\bitstreams\BA_main_t2base_CE9E9058.fs`**<br>⭐ 或固定名 **`…\build\bitstreams\LATEST.fs`**（⭐ 内容相同 ✅） | |
| **sha256** | `CE9E90587E456BB3244246CAB12C01C0A90673D33D55B54F4E8122C2792EE308` | |
| **资源** | `Register 15671` · `Lut 37832` · `Bsram 27` | |
| **时序** | ⭐ **`0 setup / 0 hold`** · ⭐ **`Fmax = 58.347 MHz`**（⭐ **+16.69%**）✅<br>🔴 **⚠️ 2026-10-01 更正**：⭐ 这个数是在**错误器件 `C2/I1`** 上测的 ⇒ ⭐ **对实物无效**；⭐ 改对器件（`C1/I0`）后同一份逻辑实测 ⭐ **`Fmax = 50.137 MHz`（⭐ 余量只剩 `+0.27%`）** ⚠️（⭐ `K-170` / `K-171`） | |
| ⭐ **门序** | ① 综合门 **0 ERROR**/50 Compiling/0 WARNING · ② 聚焦 tb **7/7**（⭐ `base_semi` **10/10** ✅）· ③ PnR **0/0 · 58.347 MHz** · ④ 全量回归 ⏳ | |
| ⭐ **归档校验** | ⭐ `fs`/`timing.txt`/`rsc.xml` **三件全部 `differs` 于 AZ** ✅ | |

---

## 一、⭐⭐⭐ 怎么触发（⭐ 发 **6 个字节**）

⭐ **接法**：⭐ `J9` 排针 · ⭐ `TX→N26` / ⭐ `RX→N25` / ⭐ `GND` · ⭐ **500000 8N1** ✅（⭐ 与 `board_probe.py` **同一条** ✅）
⭐ ⚠️ **⛔ 不需要右手板** ✅ —— ⭐ 起始音走**串口屏协议** ✅

```
71 01 xx FF FF FF
│  │  │  └────── TJC 帧尾（⭐ 固定 3 个 0xFF ✅）
│  │  └───────── 数值（⭐ = 八度 × 24 ✅）
│  └──────────── 变量序号 = 1  ⇒ ⭐ 起始音 ✅
└─────────────── 0x71 = 数值返回（⭐ TJC 的 RET_NUM ✅）
```

| ⭐ 想设成 | ⭐ `xx` | ⭐ 整帧 |
|---|---|---|
| ⭐ **C4**（⭐ 复位默认 ✅）| ⭐ `00` | ⭐ `71 01 00 FF FF FF` |
| ⭐ **C5** | ⭐ `18` | ⭐ `71 01 18 FF FF FF` |
| ⭐ **C6** | ⭐ `30` | ⭐ `71 01 30 FF FF FF` |
| ⚠️ 其它值 | — | ⭐ **被拒绝** ⇒ ⭐ 回 **C4** ✅ |

⭐ **换算**：⭐ `base_semi = 数值 / 2`（⭐ 单位：⭐ 半音 ✅）⇒ ⭐ `18`(24) ⇒ ⭐ `base_semi = 12` ⇒ ⭐ **C5** ✅

---

## 二、⭐⭐ 上板要听的

| ⭐ | ⭐ 步骤 | 🟢 绿 | 🔴 红 |
|---|---|---|---|
| **1** | ⭐ 先弹几个键（⭐ 记下音高 ✅）| ⭐ 正常 ✅ | — |
| **2** | ⭐ 发 `71 01 18 FF FF FF` | ⭐ ⭐ **所有键整体升一个八度** ✅ | 🔴 没变 / 🔴 只有部分键变 |
| **3** | ⭐ 发 `71 01 00 FF FF FF` | ⭐ **回到 C4** ✅ | 🔴 没回 / 🔴 回错 |
| **4** | ⭐ 发 `71 01 30 FF FF FF` | ⭐ **升两个八度** ✅ | 🔴 |
| **5** | ⭐ 发 `71 01 13 FF FF FF`（⭐ 非法 ✅）| ⭐ **被拒绝 ⇒ 回 C4** ✅ | 🔴 接受了 ⚠️ |
| **6** | ⭐ 连弹几个键（⭐ 升八度状态 ✅）| ⭐ 音高**仍正确**（⭐ 各键音程关系不变 ✅）| 🔴 音程乱了 |

⚠️ ⭐ **必须保持**（⭐ 若坏了说明我误伤 ⇒ ⭐ **立刻告诉我** ✅）：
- ⭐ **AZ 的鼓音高**（⭐ 嗵鼓 200 / 底鼓 60 / 军鼓 480 / 踩镲 1920 Hz ✅）
- ⭐ **AX 的键盘打鼓**（⭐ 发 `'K'` ⇒ 回 `'k'` ✅）
- ⭐ **AV 的 4 条**（⭐ 力度跟随 / 总音量 / 灵敏度 / 尾音 ✅）
- ⭐ **键 14/15 出声** · ⭐ **第一下就响** ✅

---

## 三、⭐ 顺带：其它命令（⭐ 都在本版里 ✅）

| ⭐ | ⭐ 想做什么 | ⭐ 发什么 | ⭐ 回什么 |
|---|---|---|---|
| ⭐ **切音色** | ⭐ **`I`**（⭐ `0x49` ✅）| ⭐ 无（⭐ 循环 ✅）| ⭐ BASS→GUITAR→PIANO→PAD ✅ |
| ⭐ **键盘打鼓** | ⭐ **`K`**（⭐ `0x4B` ✅）| ⭐ **`k`** ✅ | ⭐ 开/关切换 ✅ |
| ⭐ **节拍器** | ⭐ **`B`**（⭐ `0x42` ✅）| ⭐ 无 | ⭐ 开/关切换 ✅ |
| ⭐ **鼓机节奏型** | ⭐ **`D`**（⭐ `0x44` ✅）| ⭐ 无 | ⭐ 切下一型 ✅ |
| ⭐ **位置回传** | ⭐ **`N`** | ⭐ `N<轴号><5 位 hex>` ✅ | ⭐ 满按 ≈ `00744` ✅ |

⚠️ ⭐ **已知风险**（⭐ 记着 ✅）：⭐ `I`/`K`/`B`/`D` 这些**裸字母命令**与**串口屏的载荷字节**共用一条线 ⚠️
⇒ ⭐ 屏的载荷里若出现同样的字节 ⇒ ⭐ **会误触发** ⚠️ ⇒ ⭐ 已列入待办（⭐ `P0-4` ✅）

---

## 四、⭐ 记录表

| ✅ | ⭐ 项 | ⭐ 判据 | 实测 | 判定 |
|---|---|---|---|---|
| ☐ | `.fs` sha256 | `CE9E9058…2EE308` | | |
| ☐ | ⭐ 版本指纹 满按 `'N'` | 🟢 ≈**00744** ／ 🔴 04095（烧错） | | |
| ☐ | ⭐ **发 `71 01 18…` 升八度** | 🟢 整体升 ／ 🔴 没变 | | |
| ☐ | ⭐ **发 `71 01 00…` 回 C4** | 🟢 回了 ／ 🔴 | | |
| ☐ | ⭐ **发 `71 01 30…` 升两个八度** | 🟢 是 ／ 🔴 | | |
| ☐ | ⭐ **非法值被拒** | 🟢 回 C4 ／ 🔴 接受了 | | |
| ☐ | ⭐ 升八度后音程关系正确 | 🟢 正确 ／ 🔴 乱了 | | |
| ☐ | ⭐ AZ 的鼓音高仍好 | 🟢 是 ／ 🔴（⭐ 报我）| | |
| ☐ | ⭐ AX 的键盘打鼓仍好 | 🟢 是 ／ 🔴 | | |
| ☐ | ⭐ AV 的 4 条仍好 | 🟢 是 ／ 🔴 | | |

---

## 五、⚠️ 本版【已知不完美】的

| ⭐ | ⭐ 事项 |
|---|---|
| **1** | ⚠️ ⭐ **`Lut` 涨了 +2202**（⭐ `35630` → **`37832`** ⚠️ ⇒ ⭐ 占用 **63.2%**）<br>⭐ 根因：⭐ 那个八度移位是**每 lane 各一份**的变量移位器 ⚠️<br>⭐ 优化方案已定（⭐ 挪到上游 ⇒ ⭐ 只需 2 个移位器 ⚠️）⇒ ⭐ 列入 `P1-3` ✅ |
| **2** | 🔴 ⭐ **实时变调（T3）仍未实现** —— ⭐ 方案已定稿 ✅（⭐ `T3变调与推子功能状态机-设计定稿-20261001.md` ✅）|
| **3** | ⚠️ ⭐ **起始音只在【下次起音】生效** ⚠️ —— ⭐ 正在响的音**不会立刻跟着移** ✅（⭐ 因为移位在输出侧、⭐ 而锁存只在 `commit` 拍更新 ⚠️）<br>📌 ⭐ 这**正是**你之前选的"量化 ＋ 短滑音过渡"要解决的问题 ⇒ ⭐ T3 会一起做 ✅ |
