hokuu1102/Gowin2026-PolySynth/bringup/23-上板卡-AX-键盘打鼓-20261001.md

# ⭐⭐ 上板卡 · **AX**（键盘打鼓模式）· 2026-10-01

> ⭐ **要回答的唯一问题**：⭐ **发串口 `'K'`，键盘能不能当鼓垫敲？**
> **前一版（AW）的卡**：`bringup/22-上板卡-AW-音量上调-20261001.md` —— ⭐ **它全部仍适用**
> **量纲返工的卡（AV）**：`bringup/21-上板验证卡-AV-量纲返工复验-20261001.md` —— ⭐ **也全部仍适用**
> ⭐ **本版 = AV ＋ AW ＋ 新功能** ⇒ ⭐ **前面验过的都应当【仍然好】** ✅

---

## 〇、烧哪个

| ⭐ | ⭐ 项 | ⭐ 值 |
|---|---|---|
| **文件** | ⭐ **`C:\Users\hokuu\Desktop\FPGA\FPGA2026\build\bitstreams\AX_main_keydrum_46715017.fs`**<br>⭐ 或固定名 **`…\build\bitstreams\LATEST.fs`**（⭐ 内容相同） | |
| **sha256** | `4671501790CF1BA18507EE8A88D81BB202EB753CCEB7E30C95F7B2573B5CABC0` | |
| **资源** | `Register 15652` · `Lut 35394` · `Bsram 27` | |
| **时序** | ⭐ **`0 setup / 0 hold`** · ⭐ **`Fmax = 58.039 MHz`**（⭐ **+16.08%**）✅ | |
| ⭐ **门序** | ① 综合门 **0 ERROR**/50 Compiling · ② **`tb_key_drum` 75/75** · ③ PnR **0/0 · 58.039 MHz** · ④ 全量回归 ⏳ | |
| ⭐ **归档校验** | ⭐ `fs`/`timing.txt`/`rsc.xml` **三件全部 `differs` 于 AW** ✅（⭐ 防陈旧） | |

---

## 一、⭐⭐ 本版新功能：**键盘打鼓**（⭐ 一句话：⭐ 发 `'K'`）

```
⭐ 发串口  'K'  ⇒ ⭐ 回 'k'  ⇒ ⭐ 键盘变【鼓垫】
⭐ 再发    'K'  ⇒ ⭐ 回 'k'  ⇒ ⭐ 恢复【发音高】
```
⚠️ ⭐ **复位后默认 = 关**（⭐ 仍是正常发音高 ✅）

### ⭐ 键位 → 乐器（⭐ 依据你给的 `files/10-硬件/鼓垫.drawio.svg`）

| ⭐ 轴号 | ⭐ 板 | ⭐ 图上位置 | ⭐ 乐器 | ⭐ 音高 | ⭐ 听感 |
|---|---|---|---|---|---|
| **0 ~ 3** | ⭐ 板1（左/下）| ⭐ 右两列 | ⭐ **嗵鼓** | ⭐ **200 Hz** | ⭐ 中低频"嗵"（⭐ 有音高，⭐ 下滑很轻）|
| **4 ~ 7** | ⭐ 板1（左/下）| ⭐ 左两列 | ⭐ **底鼓** | ⭐ **60 Hz** | ⭐ 最低"咚"（⭐ **全深度**扫频 ⇒ 明显下坠）|
| **8 ~ 11** | ⭐ 板2（右/上）| ⭐ 右两列 | ⭐ **军鼓** | ⭐ **480 Hz** | ⭐ 中频"啪"（⭐ 比原来亮得多）|
| **12 ~ 15** | ⭐ 板2（右/上）| ⭐ 左两列 | ⭐ **踩镲** | ⭐ **1920 Hz** | ⭐ 高频"嘶" |

⭐⭐ **2026-10-01 晚：音高已【拉开】**（⭐ 用户上板反馈"4 个鼓听不太出来区分度"）
- ⭐ 相邻音程：⭐ **20.8 / 19 / 32 个半音**（⭐ 二次拉开后）
- ⭐ **军鼓 192 → 480 Hz**（⭐ 与嗵鼓 4.2 → **19** 个半音 ✅）
- ⭐ **二次拉开**：⭐ 底鼓 70 → **60** · 嗵鼓 160 → **200** ⇒ ⭐ 比 **3.33×**（**20.8** 个半音）
  ⭐ 并同时把嗵鼓的扫频深度从 1/4 调到 **1/8**（⭐ 与底鼓"全深度"的包络差更远）
- ⚠️ ⭐ **踩镲【没有抬】** —— ⭐ 实测 2400/3200 Hz 会让 `tb_wavetable_bank` 的
  "**鼓必须仍像噪声**"判据变红（⭐ 噪声表循环太快就变音调）✅
- ⭐ **力度也改了**：⭐ 每件有**基础力度**（⭐ 底鼓 230 · 军鼓 210 · 嗵鼓 200 · 踩镲 175）
  ⇒ ⭐ `vel = max(键盘力度, 基础力度)` ⇒ ⭐ **轻敲也够响，⭐ 重敲能到 255** ✅

⭐ **分配理由（⭐ 按你说的"使用频率均衡"）**：⭐ 使用频率 **踩镲 > 军鼓 > 底鼓 > 嗵鼓**
⇒ ⭐ **右手拿第 1、3 常用；左手拿第 2、4 常用** ⇒ ⭐ **每只手都有一件高频 + 一件低频** ✅

### ⭐ 打鼓模式下**自动做到**的三件事（⭐ ⛔ 你不用管）

| ⭐ | ⭐ 行为 | ⭐ 为什么 |
|---|---|---|
| **1** | ⭐ 走**鼓的包络**（⭐ 敲一下就衰减，⛔ 不是持续音）| ⭐ 事件标了 `SRC_AUX(3)` ⇒ ⭐ 进保留池 + perc 包络 ✅ |
| **2** | ⭐ 用**固定的鼓音色** | ⭐ 与"当前键盘音色"**彻底解耦** ⇒ ⭐ 切音色**不影响鼓** ✅ |
| **3** | ⭐ **力度仍然有效** | ⭐ 敲得重 = 鼓更响（⭐ 与手弹同一套力度）✅ |

---

## 二、⭐⭐ 上板怎么测（⭐ 全是"听得见"的判据）

| ⭐ | ⭐ 步骤 | 🟢 绿 | 🔴 红 |
|---|---|---|---|
| **1** | ⭐ 发 `'K'` | ⭐ 回 **`'k'`** | 🔴 无回包 / 回别的字节 |
| **2** | ⭐ 敲**轴 0~3** 的键 | ⭐ **"嗵"**（⭐ 中低频，⭐ ≈150 Hz）| 🔴 仍是音高 / 无声 |
| **3** | ⭐ 敲**轴 4~7** | ⭐ **"咚"**（⭐ 最低，⭐ ≈75 Hz）| 🔴 同上 |
| **4** | ⭐ 敲**轴 8~11** | ⭐ **"啪"**（⭐ 中频，⭐ ≈200 Hz）| 🔴 同上 |
| **5** | ⭐ 敲**轴 12~15** | ⭐ **"嘶"**（⭐ 高频，⭐ ≈2000 Hz）| 🔴 同上 |
| **6** | ⭐ **敲得重 / 敲得轻** | ⭐ 音量**跟着变** | 🔴 力度无反应 |
| **7** | ⭐ **切键盘音色**（⭐ 发 `'I'`）| ⭐ 鼓的音色**不变** | 🔴 鼓音色跟着变 |
| **8** | ⭐ 再发 `'K'` | ⭐ 回 `'k'`，⭐ **恢复发音高** | 🔴 仍是鼓 |

⚠️ ⭐ **必须保持**（⭐ 若坏了说明我误伤）：
- ⭐ **AV 修的 4 条**（力度跟随 / 总音量 / 灵敏度 / 尾音）
- ⭐ **AW 的音量**（鼓机/节拍器比 AV 响）
- ⭐ **键 14/15 出声** · ⭐ **第一下就响**

---

## 三、⚠️ 一个**已知限制**（⭐ 用之前要知道）

| ⭐ | ⭐ 限制 | ⭐ 怎么办 |
|---|---|---|
| 🔴 | ⭐ **鼓垫与"源 B（节拍器/鼓机）"共用【保留池】** —— ⭐ 两者都是 `SRC_AUX(3)` ⇒ ⭐ 共享 **5 个 voice**<br>⇒ ⭐ **手敲鼓 + 鼓机同时响 ⇒ 最多 5 音**（⭐ 超了会丢）| ⭐ **手敲鼓时先发 `'B'` 关掉源 B** ✅（⭐ 敲完再开）|

⚠️ ⭐ 另：⭐ 本版 `Lut` **35394**（⭐ 比 AW 的 35697 **少 303**）—— ⭐ 是**综合器重优化**，
⭐ **行为已由 `tb_key_drum` 75/75 验过** ✅（⭐ 且 `Register` **+1** = 新加的模式寄存器 ✅）

---

## 四、⭐ 沿用前两张卡（⛔ 不重复列）

⭐ 以下**全部仍然适用**：
- ⭐ **AV 卡**（`bringup/21-…`）：⭐ 版本指纹（⭐ 满按 `'N'` 应读 **≈00744**）· ⭐ `T1`~`T8` 判据 · ⭐ 串口接法 · ⭐ 铁律
- ⭐ **AW 卡**（`bringup/22-…`）：⭐ 鼓机/节拍器的音量期望
- ⭐ 串口：⭐ **`J9` 排针** · `TX→N26` / `RX→N25` / `GND` · **500000 8N1**（⛔ 板载 USB-C 走不通）

---

## 五、⭐ 记录表

| ✅ | ⭐ 项 | ⭐ 判据 | 实测 | 判定 |
|---|---|---|---|---|
| ☐ | `.fs` sha256 | `46715017…CABC0` | | |
| ☐ | ⭐ 版本指纹 满按 `'N'` | 🟢 ≈**00744** ／ 🔴 04095（烧错） | | |
| ☐ | ⭐ 发 `'K'` 回 `'k'` | 🟢 有 ／ 🔴 无 | | |
| ☐ | ⭐ 轴 0~3 嗵鼓 | 🟢 中低频"嗵" ／ 🔴 | | |
| ☐ | ⭐ 轴 4~7 底鼓 | 🟢 最低"咚" ／ 🔴 | | |
| ☐ | ⭐ 轴 8~11 军鼓 | 🟢 中频"啪" ／ 🔴 | | |
| ☐ | ⭐ 轴 12~15 踩镲 | 🟢 高频"嘶" ／ 🔴 | | |
| ☐ | ⭐ 力度跟随 | 🟢 跟着变 ／ 🔴 无 | | |
| ☐ | ⭐ 切音色不影响鼓 | 🟢 不变 ／ 🔴 变了 | | |
| ☐ | ⭐ 再发 `'K'` 恢复 | 🟢 恢复音高 ／ 🔴 | | |
| ☐ | ⭐ **AV 的 4 条仍好** | 🟢 全好 ／ 🔴 有回退（⭐ 报我） | | |
| ☐ | ⭐ **AW 的音量仍好** | 🟢 是 ／ 🔴 | | |
| ☐ | ⭐ 键 14/15 ＋ 第一下就响 | 🟢 都好 ／ 🔴（⭐ 报我） | | |

---

## 六、⚠️ 本版【故意没做】的

| ⭐ | ⭐ 事项 |
|---|---|
| **1** | ⭐ **需求 B**（打鼓 loop → 量化 → 存进鼓机）—— ⭐ 你裁定**下一轮做** ✅ |
| **2** | ⭐ **需求 C**（释放 looper ＋ 同时录旋律）—— ⭐ 随 B 一起 ✅ |
| **3** | ⚠️ ⭐ 那 4 个 `phase_inc` 在 `top.v` 是**有意重复**的 ⇒ ⭐ 单一来源修法**留待后续**（⭐ 本轮用 T3 判据守住）✅ |
| **4** | ⚠️ ⭐ 变异记录里 **M1/M3/M4/M5/M6 尚未实跑**（⭐ **M2 已实跑并变红** ✅）|
| **5** | 🔴 ⭐ HDMI 接入主工程 —— ⭐ 你裁定"**等队友打通**" ✅ |
