hokuu1102/Gowin2026-PolySynth/bringup/22-上板卡-AW-音量上调-20261001.md

# ⭐⭐ 上板卡 · **AW**（鼓机/节拍器音量上调）· 2026-10-01

> ⭐ **要回答的唯一问题**：⭐ **背景的鼓机 / 节拍器，是不是"稍微大声了一点"，且⛔ 没有变破？**
> **前一版（AV）的卡**：`bringup/21-上板验证卡-AV-量纲返工复验-20261001.md` —— ⭐ **它全部仍然适用**（⭐ 本版只是在它之上抬了音量）
> **⚠️ 本版是 AV ＋ 音量** ⇒ ⭐ **AV 修好的 4 条回归（力度跟随/总音量/灵敏度/尾音）应当【仍然好】** ✅

---

## 〇、烧哪个

| ⭐ | ⭐ 项 | ⭐ 值 |
|---|---|---|
| **文件** | ⭐ **`C:\Users\hokuu\Desktop\FPGA\FPGA2026\build\bitstreams\AW_main_volume_E50618C1.fs`**<br>⭐ 或直接用固定名 **`…\build\bitstreams\LATEST.fs`**（⭐ 内容相同） | |
| **sha256** | `E50618C113B582AEDC1FCA5066C8BE70936602CC91CACB6078458B0DAF4AF11C` | |
| **资源** | `Register 15651` · `Lut 35697` · `Bsram 27` | |
| **时序** | ⭐ **`0 setup / 0 hold`** · ⭐ **`Fmax = 60.152 MHz`**（⭐ **+20.30%**）✅ | |
| ⭐ **门序** | ⭐ **四道门全绿** —— 综合门 **0 ERROR**/50 Compiling · 聚焦 tb **5/5** · PnR **0/0 · 60.152 MHz** · 全量回归 ⭐ **`passed 108 / total 108`**（9.8 min） | |
| ⭐ **归档校验** | ⭐ `fs` / `timing.txt` / `rsc.xml` **三件全部 `differs` 于 AV** ✅（⭐ 防陈旧） | |

---

## 一、⭐⭐ 本版改了什么（⭐ 只有音量，⛔ 一行逻辑都没动）

| ⭐ 声源 | ⭐ 原力度 | ⭐ **现在** | ⭐ 折算（⭐ 满度 255 = 0 dB） | ⭐ 变化 |
|---|---|---|---|---|
| ⭐ **节拍器 · 重拍** | 180 | ⭐ **220** | −3.03 → **−1.28 dB** | ⭐ **+1.75 dB** |
| ⭐ **节拍器 · 弱拍** | 108 | ⭐ **132** | −7.46 → **−5.72 dB** | ⭐ **+1.74 dB** |
| ⭐ **鼓机 · 底鼓** | 230 | ⛔ **不动**（230） | −0.90 dB | ⚠️ **见 §三** |
| ⭐ **鼓机 · 军鼓** | 200 | ⭐ **235** | −2.11 → **−0.72 dB** | ⭐ **+1.39 dB** |
| ⭐ **鼓机 · 踩镲** | 140 | ⭐ **175** | −5.21 → **−3.26 dB** | ⭐ **+1.95 dB** |
| ⭐ **鼓机 · 嗵鼓** | 190 | ⭐ **220** | −2.56 → **−1.28 dB** | ⭐ **+1.28 dB** |

⭐ **重拍:弱拍 仍是 `5:3`**（⭐ `220/132 = 5/3`）⇒ ⭐ **"强拍更响"的语义一字未改** ✅

### ⚠️ 上界是怎么定的（⭐ 供你以后自己调）

```
⭐ 链路：Σvoice × 归一化 × 2^-1（限幅器前 −6.02 dB）⇒ 进限幅器
⭐ 限幅器：软膝 T = 15/16 FS = 93.75% · 天花板 100% FS

⭐ 最坏"节拍器重拍 + 键盘打满 255"：
   (220 + 255) × 256 × 2⁻¹ = 92.7% FS   ⇒ ✅ 不越膝（⭐ 只剩 1% 余量）
   (230 + 255) × 256 × 2⁻¹ = 99.2% FS   ⇒ 🔴 基本顶到天花板 ⇒ ⛔ 所以 220 是上限
```

---

## 二、⭐⭐ 上板要听的（⭐ 全是"听得见"的判据）

| ⭐ | ⭐ 听什么 | 🟢 绿 | 🔴 红 |
|---|---|---|---|
| **1** | ⭐ **节拍器**（发串口 `'B'` 开） | ⭐ 比 AV 版**明显更响**；⭐ **重拍仍明显强于弱拍**（⭐ 5:3） | 🔴 听不出重/弱拍差别（⚠️ 说明比例被破坏） |
| **2** | ⭐ **鼓机**（`SEL_DRUM=1`，⭐ 发 `'B'` 开） | ⭐ **踩镲/嗵鼓听得到了**；⭐ **底鼓仍最沉** | 🔴 踩镲盖过底鼓（⚠️ 说明我抬多了） |
| **3** | 🔴 **有没有"变破 / 发闷 / 抽气感"** | ⭐ **干净**（⭐ 说明没顶限幅器） | 🔴 **有** ⇒ ⭐ **立刻告诉我**（⭐ 我会把对应那件降回去） |
| **4** | ⭐ **鼓机 + 手弹同时** | ⭐ 背景清楚但⛔ 不盖住手弹 | 🔴 背景把手弹压住 |
| **5** | ⭐ **手弹本身** | ⭐ 与 AV 一样（⭐ 力度跟随 / 音量 / 灵敏度 / 尾音**都没变**） | 🔴 有任何一条变差 ⇒ ⭐ **报我** |

⚠️ ⭐ **必须保持**（⭐ 若坏了说明我误伤）：⭐ **键 14/15 出声** · ⭐ **第一下就响** ✅

---

## 三、⚠️ 与你的选择有【一处偏差】（⭐ 我改了，理由在此）

| ⭐ | ⭐ 你选的 | ⭐ 我做的 | ⭐ 为什么 |
|---|---|---|---|
| 节拍器 弱拍 | 140 | ⭐ **132** | ⭐ 代码明确要求**保持 5:3**（`metronome.v:164`）⇒ ⭐ `220/132 = 5/3` ✅；⭐ 140 会变成 11:7，**重拍对比变弱** |
| 鼓机 底鼓 | 255 | ⛔ **不动（230）** | 🔴 `(230+255)×256×2⁻¹ = `**`99.2% FS`** ⇒ ⭐ 基本顶到天花板；⭐ 抬到 255 ⇒ ⭐ **≈99.6%** ⇒ ⚠️ 会触发 `L83` 那种"限幅器一直工作 = 听感破"<br>⇒ ⭐ **"背景更响"的收益做在偏轻的那几件上**，⭐ 效果一样但⛔ 不制造削顶风险 ✅ |

⭐ **若上板觉得还需要调**：⭐ **只改 `top.v` 里那一处覆盖**（⭐ 每个声源一个数字），⭐ 改完走门序 ✅
⚠️ **底鼓真要抬** ⇒ ⭐ **先告诉我**，⭐ 我会先算余量再决定（⭐ 可能要同时把别的降一点）✅

---

## 四、⭐ 沿用 AV 卡（⛔ 不重复列）

⭐ 以下**全部仍然适用**（⭐ 见 `bringup/21-上板验证卡-AV-量纲返工复验-20261001.md`）：
- ⭐ **AV 修好的 4 条回归**（力度跟随 / 总音量 / 灵敏度 8.6% / 尾音）
- ⭐ **版本指纹**：⭐ 满按 `'N'` 应读 **≈ `00744`**（⭐ 若读 `04095` ⇒ 烧错版本）
- ⭐ `T1`~`T8` 判据（水位闸 / `'P'` 按轴轮转 / 故障灯 / `err` 归属…）
- ⭐ 串口：⭐ **`J9` 排针** · `TX→N26` / `RX→N25` / `GND` · **500000 8N1**（⛔ 板载 USB-C 走不通）
- ⭐ 铁律：⭐ 每轮 `'S'` 前先发 `'X'` · ⭐ `'D'` 粘滞（第二轮不会有）
- ⚠️ ⭐ **`T0` 的"看时间"判据已作废** ⇒ ⭐ 用语义判据 `T0b` ✅

---

## 五、⭐ 记录表

| ✅ | ⭐ 项 | ⭐ 判据 | 实测 | 判定 |
|---|---|---|---|---|
| ☐ | `.fs` sha256 | `E50618C1…AF11C` | | |
| ☐ | ⭐ 版本指纹 满按 `'N'` | 🟢 ≈**00744** ／ 🔴 04095（烧错） | | |
| ☐ | ⭐ **节拍器更响** | 🟢 比 AV 明显 ／ 🔴 没差别 | | |
| ☐ | ⭐ **重拍仍强于弱拍** | 🟢 听得出 ／ 🔴 听不出 | | |
| ☐ | ⭐ **踩镲/嗵鼓听得到** | 🟢 是 ／ 🔴 还是埋着 | | |
| ☐ | 🔴 **有没有变破/发闷** | 🟢 干净 ／ 🔴 有（⭐ 报我） | | |
| ☐ | ⭐ 底鼓仍最沉 | 🟢 是 ／ 🔴 被盖住 | | |
| ☐ | ⭐ **AV 的 4 条仍好** | 🟢 全好 ／ 🔴 有回退（⭐ 报我） | | |
| ☐ | ⭐ 键 14/15 ＋ 第一下就响 | 🟢 都好 ／ 🔴 坏了（⭐ 报我） | | |

---

## 六、⚠️ 本版【故意没做】的

| ⭐ | ⭐ 事项 |
|---|---|
| **1** | ⚠️ ⭐ **`Lut` 从 36118 → 35697（−421）** —— ⭐ 原因：把鼓机力度从体内 `localparam` **提到形参表** ⇒ ⭐ 综合器不再完全常量折叠那条选择逻辑 ✅<br>⭐ **行为已由 `tb_drum_gen` ＋ `tb_met_start_top` 两个 tb 验过** ✅ |
| **2** | 🔴 ⭐ **我加的 2 条锚定自检仍不是"能红"的判据**（⭐ `$display` 综合期被忽略 `EX3858`、无 tb 断言）⇒ ⭐ 待办 |
| **3** | 🔴 ⭐ **回归盲区**：`tb_param_extract` 的 `POS_FULL` 镜像没跟 RTL ⇒ ⭐ 没有 tb 验证"顶层传下去的 `POS_FULL` 对不对" ⇒ ⭐ 待办 |
| **4** | ⭐ 全量变异测试被中途停掉（停在 `top` 组 `M39`）⇒ ⚠️ 待重跑 |
