hokuu1102/Gowin2026-PolySynth/bringup/20-上板验证卡-AU-20261001.md

# ⭐⭐ 上板验证卡 · **AU**（2026-10-01）

> **要回答的唯一问题**：⭐ **AU 这一版修好的东西，上板到底成不成立？**
> ⚠️ **本卡取代** `bringup/18-上板验证卡-功能修复-20260930深夜.md`（⭐ 那份是给 **AM** 写的，
> 它的 `EVT_TRIG_TH=64` · `STILL_TOL=8` · "键 14/15 无声是已知缺口" · "门槛 5%" **全部已过时**）。
> **接线/烧录**：⭐ 见 `bringup/16-上板操作手册-20260929.md`（⭐ 串口走 **`J9` 排针**，⛔ 不是板载 USB-C）

---

## 〇、⭐⭐ 烧哪个

| ⭐ | ⭐ 项 | ⭐ 值 |
|---|---|---|
| **文件** | ⭐ **`C:\Users\hokuu\Desktop\FPGA\FPGA2026\build\bitstreams\AU_main_declfix_B0C094D.fs`** | |
| **sha256** | `B0C094D7FE36F129BD873BDE799546289587FEE83C8DDF4AE67A7BAE74376E50` | |
| **大小 / 时间** | `18,528 KB` · `2026-10-01 05:42:31` | |
| **时序** | ⭐ **`0 setup / 0 hold`** · ⭐ **`Actual Fmax = 62.888 MHz`**（⭐ **+25.78%**）⇒ ⭐ **远超 3% 门槛（51.5 MHz）** ✅ | |
| **资源** | `T_Register=15650` · `T_Lut=35752` · `T_Bsram=27` · `T_MULTALU27X18=38` | |

### ⭐ 为什么是它（⭐ 已核实，⛔ 不是"最新的那个"）

⭐ **`git diff --stat f682fe3 HEAD -- rtl/ constr/` = 空** —— ⭐ 即
**AU 构建时的 `rtl/`＋`constr/` 与当前 HEAD 逐字节一致** ✅
（`f682fe3` 之后只改了 `sim/`、`tools`、`docs`：`tb_all_par.ps1` ＋ 110 个 `.compile.log` ＋ 文档）

⇒ ⭐ **AU 就是当前树的位流，⛔ 不存在"烧旧代码"的风险** ✅
⇒ ⭐ 它也是**余量最好的一版**（`Fmax` 62.888 MHz，8 份归档里最高）✅

⚠️ **本卡不烧其它 `.fs`**：⭐ `AT`（fault_led）· `AS`（scale_check）· `AR`（adcfarm_hold）·
`AQ`（p_probe）· `AP`（vel4095/sdcfix）· `AO`（poolsrc）· `AN`（n13/thr）⭐ **都是 AU 的前置版本**
—— ⚠️ 只有在 **§七 需要"对照红"** 时才回烧它们。

---

## 一、⭐⭐ AU 相对 AM 多了什么（⭐ 决定"验哪些功能"）

⚠️ **上次上板验的是 AM**（`deliverA_stage3` = `7a32935` ＋ `SEL_DRUM=1`）。
⭐ **AU 在它之上叠加了 7 个单元**：

| ⭐ | ⭐ 单元 | ⭐ 改了什么 | ⭐ 上板能验吗 |
|---|---|---|---|
| **B** | ⭐ **BATCH 2 阈值量纲** | `EVT_TRIG_TH 64 → 205`（**5.0%**）· `EVT_REL_TH 32 → 102`（2.5%） | ⭐ **手感**（⭐ 阈值表） |
| **C** | ⭐⭐ **BATCH 3 池按来源** | `pool_mask`/`voice_drum_o` 由"按轴号"改为"按 `SRC_AUX`" | ⭐⭐ **键 14/15 出声** ← 🔴 **用户报的问题 1** |
| **D** | ⭐ **BATCH 4 力度量纲** ＋ 🔴 **`.sdc` 过紧修复** | `POS_FULL 744 → 4095`（`= CALIB_FULL`）· 斜率 `263 → 48` | ⭐ **力度跟行程** ＋ ⭐ **`Fmax` 52 → 58** |
| **E** | ⭐ **BATCH 8.1 `'P'` 按轴轮转** | ⭐ `'P'` 不再恒读片 0 ⇒ ⭐ **16 次一轮覆盖两片** | ⭐⭐ **`'P'` 现在能诊断板 2** ✅ |
| **F** | ⭐ **`adc_farm` 片 1 保持** | ⭐ 新增 `shadow_hold`（⛔ 不清零）⇒ ⭐ 片 1 数据**不再只在 ~1 µs 内有效** | ⭐ **`'P'` 读片 1 拿得到非零值** |
| **G** | ⭐ **BATCH 8.2 量纲自检** | ⭐ `CALIB_FULL` 单一来源 ＋ **3 条综合期自检** | ⛔ **算法/常量层，⛔ 上板不可见**（⚠️ 它保证的是"错配会被拦下"） |
| **H** | ⭐ **BATCH 8.3 故障指示** | ⭐ **有故障 ⇒ 心跳灯快闪**（`fault_sticky` sticky，只有复位才清） | ⭐ **看灯** ✅ |
| **I** | ⭐ **声明作用域修复** | ⭐ `fault_any_w` 提到模块级（清 `implicit definition`） | ⛔ 上板不可见（⭐ 它让 `Fmax` 从 53.2 → **62.9**） |

---

## 二、⭐ 本版编译期开关与量纲（⭐ 实测值 —— 决定哪些判据【可达】）

| ⭐ 开关 / 常量 | ⭐ AU 的值 | ⭐ 出处 | ⚠️ 对验证的影响 |
|---|---|---|---|
| `SEL_DRUM` | **1** | `top.v:120` | ⭐ 源 B = **鼓机**（节拍器被综合扫掉） |
| `METRONOME_ON` | **1** | `top.v:161` | 编译期总闸开 |
| `met_on_r` 复位值 | **0** | `top.v:456-470` | ⭐⭐ **源 B 上电静音** ⇒ ⛔ 鼓机不会自己响，⭐ **要发 `'B'`** |
| `DPOS_DIAG` | **0** | `top.v:185` | 🔴 `'Q'` 诊断包**关** |
| `SCORE_UART_ENABLE` | **1** | `top.v:3070` | ⭐ 曲谱 ＋ looper 同时可用 |
| `RIGHT_ADC_ENABLE` | **0** | `top.v:277` | ⛔ 颤音/推子**不可达** |
| `VEL_AXIS_N` | **16** | `top.v:2340` | ✅ 两块左手板都在位 ⇒ 轴 0~15 |
| `SPAN_CHECK_BOTH` | **1** | `top.v:1507` | ⭐ 两片 `err` 都上报 ⇒ **T4 可达** |
| ⭐ `EVT_TRIG_TH` | ⭐ **205**（= **5.0%** of 4095） | `top.v:2283` | ⭐ **修前是 64（1.6%）** ⇒ ⭐ 手感差异明显 |
| ⭐ `EVT_REL_TH` | ⭐ **102**（2.5%） | `top.v:2284` | ⭐ 保持 **2:1 迟滞** |
| ⭐ `CALIB_FULL` / `.POS_FULL` | ⭐ **4095**（单一来源） | `top.v:2295` · `:2895` | ⭐ **修前 744** ⇒ ⭐ `'N'` 满按应到 **4095** |
| ⭐ `STILL_TOL`（autotare） | ⭐ **48**（⭐ 修前 **8**） | `top.v:1646` | ⭐⭐ **旧卡的 R1 风险（全通道超时）已消除** ✅ |
| `STILL_FRAMES` / `WAIT_MS` | **4** / **1000** | `top.v:1654-1655` | ⭐ 每轴最快 **2 ms** ⇒ 8 轴 ≈ **7 ms** |
| `SPAN_STABLE_TOL` | **48** | `top.v:271` | ⭐ 与 autotare 侧**已对齐** ✅ |
| `INVERT_AXIS` | **1** | `top.v:1738` | `pos = 4095 − raw` |

---

## 三、🔴🔴 先做**这一个**测量：`t` → `T` 的时间差（**T0**）

> ⭐⭐ **为什么先做它**：⭐ **一行判据同时覆盖三件事**，⭐ 而且**几十秒就能做完**。

```powershell
python tools\board_probe.py <COM口> --send T        # ⭐ 看 t 与 T 的时间戳差
```

| ⭐ 实测 | ⭐ 判定 |
|---|---|
| ⭐ **≈ 7 ms** | ✅ **正确**（静止守卫在工作 ＋ `WAIT_CLK` 没溢出 ＋ `STILL_TOL=48` 够松） |
| 🔴 **≈ 0.3~0.5 ms** | 🔴 **溢出版 / 无守卫** —— `WAIT_CLK` 回绕 ⇒ **一个 `tare` 都不发，却照回 `T`** |
| 🔴 **≈ 8 s** | 🔴 **全通道静默超时**（⭐ AU 下**不该出现** —— `STILL_TOL` 已是 48） |

**⚠️ 最重要的一条认知**：⭐ **两种失败【都照回 `T`】** ⇒ ⛔ **看到 `T` 绝不能判定"autotare 成功"**。

### 🔴🔴 **T0b（⭐ 主判据）** —— 2026-10-01 实测更正：**T0 的"看时间"在本机测不出来**

⭐ **实测结论**：⭐ **PC 串口驱动的 `LatencyTimer`（本机 ≈10~16 ms）比 `t→T` 的 7 ms 还长**
⇒ ⭐ 两个字节被**批量投递** ⇒ ⭐ 连 `'X'` 的回包都显示 `@0.0 ms`
⇒ 🔴 **本机用 Python 读串口【分辨不了 🟢7 ms 与 🔴0.5 ms】**
（⭐ 要测那个时间得**示波器**，或把串口驱动的 `LatencyTimer` 调低 —— ⚠️ 属系统配置，⛔ 别随手改）
⇒ ⭐ **所以主判据换成【语义】的 T0b**（⛔ 不依赖时间分辨率）：

```powershell
# ⭐ 采集期间【请勿碰任何键】，让 16 轴都处于松手静止态
#   （先发 T 触发 tare，再连发 16 次 N 读 16 轴）
python tools\board_probe.py <COM口> --send "T,@0.6,N,N,N,N,N,N,N,N,N,N,N,N,N,N,N,N"
```

⭐ **回包格式**：`N` ＋ **轴号(1 hex)** ＋ **校准后 `pos`(5 hex)** ＋ `CR LF` = **8 字节**，共 **128 字节**

| | ⭐ 观察 | ⭐ 含义 |
|---|---|---|
| **🟢 绿** | ⭐ 16 轴**全 ≈ `00000`**（⭐ 允许个位数 `00001` —— 那是松手静止噪声） | ⭐ **`zero` 被成功捕获** ⇒ ⭐ **tare 真的发出去了** |
| **🔴 红** | ⭐ 16 轴**全 ≈ `01023`** | ⭐ **zero 全没写**（被跳过 ⇒ 全体挂音）**或** `WAIT_CLK` 回绕 ⇒ **一个 `tare` 都不发** |

⭐⭐ **为什么 T0b 能替代 T0**：⭐ `t→T` 那个"0.5 ms 失败模式"的定义就是
**"一个 `tare` 都不发，却照样回 `T`"** ⇒ ⭐ **只要 T0b 绿，那个模式就【已被排除】** ✅
⚠️ 但它**证明不了**"守卫/" `STILL_TOL` 参数合适" ⇒ ⭐ 那个要靠 **T6 的 E2/E3**
（⭐ 那里的时间差是 **8 s** 量级 ⇒ ⭐ **本机测得出** ✅）。

📌 **本卡 2026-10-01 的实测记录**（⭐ **COM32** · 500000 8N1 · AU 候选位流）：
```
X => 78(x)@0.0ms                    # ⭐ 解析器活着、帧外认命令 ✅
T => 74(t)@0.0ms  54(T)@0.0ms        # ⭐ 回包齐全（t=受理 tare，T=完成）
T0b: N0 00000  N1 00000  N2 00001  N3 00000
     N4 00001  N5 00001  N6 00000  N7 00001
     N8 00000  N9 00000  NA 00000  NB 00000
     NC 00000  ND 00000  NE 00000  NF 00000
     ⇒ 🟢 绿（16 轴全标上；🔴 若未标定应读 ≈01023）
```
⚠️ ⭐ **仍未确认的一点**：⭐ 串口上**看不出板上烧的是哪一版**。
⭐ **版本指纹（需你配合）**：⭐ 某个键**按到底** ⇒ 连发 `'N'` 读该轴
⇒ ⭐ 读 **≈`04095`** = **AU 的新量纲**（`CALIB_FULL=4095`）；⭐ 读 **≈`00744`** = **旧量纲**（AM 及更早）。

---

## 四、⭐⭐⭐ 必验：两件"具体症状"

### ① 🔴🔴 **键 14/15（G#3 / A#3）出不出声** ← 用户报的问题 1

> ⭐ **这是本版最该验的一条** —— ⭐ `BATCH 3`（池按来源）就是为它做的。

| ⭐ | ⭐ 操作 | 🟢 绿 | 🔴 红 |
|---|---|---|---|
| 1 | ⭐ 逐个按 **16 个键**（板 1 的 8 键 ＋ 板 2 的 8 键） | ⭐ **16 个键各自出声** | 🔴 **键 14/15 无声**（= 修前形态） |
| 2 | ⭐ 重点复按 **14 / 15** 各 3 次 | ⭐ 每次都出声 | 🔴 怎么按都不响 |
| 3 | ⭐ **同时按**几个键（≥5 个） | ⭐ 都在响、不被抢 | 🔴 有键被"吃掉" |

⭐ **依据**：`note_manager.v:509/523` —— `pool_mask` 与 `voice_drum_o` 现在由
**`cur_src == SRC_AUX`** 决定（⭐ 修前是 `cur_axis >= 14` ⇒ ⭐ 物理键 14/15 **被当鼓机抢进保留池**）。

### ② ⚠️⚠️ **上一次上板【没解释】的症状**：自检和弦响完后，**前几下按键不响**

> ⭐ 依据：`tb/e2e/tb_demo_stall_diag.sv:9-14` —— ⭐ **用户实测、可复现、两次上电一致**：
> ① 自检和弦正常响 ✅ ② ⭐ **和弦响完后前几下按键全不响**
> ③ ⭐ **要按十几下才第一次出声，且"按序继承"（先按的先响，音高滞后于按键）**
> ④ 同轴按 / 异轴按表现一样 ⑤ 另有挂音
> 🔴 **仿真里【没有复现】**（⭐ 每次按键都在自己轴上 gate 到 voice、零丢事件）
> ⚠️ **但它把时序缩短了**（`DEMO_NOTE_DELAY` 10000 vs 板上 2,000,000）
> ⇒ ⛔ **不能据此宣布"板上症状不存在"**

| ⭐ | ⭐ 操作 | 🟢 绿 | 🔴 红 |
|---|---|---|---|
| 1 | ⭐ 上电 ⇒ 等自检和弦**响完**（+ 串口出 `T`）⇒ ⭐ **按第一下** | ⭐ **立刻出声** | 🔴 **不响** ⇒ ⭐ **命中该症状** |
| 2 | ⭐ 若第 1 下不响 ⇒ ⭐ **数**按到第几下才出声 | ⭐ 第 **1** 下 | 🔴 要按 **十几下**（⭐ 记下确切次数） |
| 3 | ⭐ 出声顺序 vs 按键顺序 | ⭐ 一致 | 🔴 **"按序继承"**（先按的后响、音高滞后） |
| 4 | ⭐ **复位**后重做 1~3 | ⭐ 与上电一致 | 🔴 只有复位后才正常（⭐ 那就是"复位 ≠ 冷启动"） |
| 5 | ⭐ 挂音：松开后是否还响 / 按别的键能否消掉 | ⭐ 正常衰减、不挂音 | 🔴 挂音 |

⭐ **若命中**：⭐ 请记下**确切次数**与**是否"按序继承"** —— ⭐ 这两点直接决定是
**`seq_arb` 排队**还是**零点记错**（⭐ 前者"按序继承"、后者不继承）。

---

## 五、⭐ 判据 T1 ~ T8（⭐ 每条都能红 —— ⛔ 不能红的不是判据）

> ⭐ 每条都写出 🔴 **红长什么样**。⭐ 上板时**先确认那个"红"是可分辨的**。
> 📌 依据：全局 `0.11` 第 2 步 ＋ 经验库 `C83`（**探针假绿**）。

### T1 · ⭐⭐ 水位闸：一次**失败的 `'S'`** 不得毁掉已标定的归一化

⭐ **确定性造法**：⭐ **按住【板2】某个键、【静止不动】** ⇒ 发 `'T'` ⇒ 等 `T` ⇒ 松手 ⇒ 发 `'X'` ⇒ 再发 `'S'`
（⭐ 必然 `err`：tare 两片广播，而片1 的 `zero` 被记成"按下位" ⇒ 松手后 `raw < zero`）

| | ⭐ 观察 |
|---|---|
| **🟢 绿** | ⭐ 标定后**松手 `'N'` ≈ `0000`**、**满按 `'N'` ≈ `4095`**；⭐ 造一次失败后再发 `'S'` ⇒ ⭐ 满按**仍 ≈ 4095** |
| **🔴 红** | ⭐ 失败后满按 **掉到 ≈ `0744`**（⭐ `gain_r` 被清成 1.0 = **修前形态**） |

⚠️ `MAX_TRAVEL` 是**静默上界** ⇒ ⭐ 先读 `'P'` 确认行程再解读。

### T2 · ⭐ `at_done` 门控：上电/复位后 **200 ms 窗口**内 `'S'` 必被拒

```powershell
# ⭐ 上电（或按板载复位键 AA13）的【同时】跑这条，抓 1.2 秒
python tools\board_probe.py <COM口> --send S --follow S --follow-gap 0.02 --follow-count 60
```
🟢 `! ! ! … !` **`T`** `s` …（⭐ `T` 之前**全是 `!`**，且每个 `!` **后面没有轴号**）
🔴 ⭐ **第一个回包就是 `s`** ⇒ 门控没生效
⛔ **警告**：分歧窗口**只有 0~200 ms**。⭐ 在 500 ms（和弦还在响）发 `'S'` ⇒ **两版都受理、不区分**。

### T3 · ⭐ 水位闸 B：**复位后** `'N'` 应为"未标定"态

> 🔴 ⭐ **真·冷【上电】时的 `'N'` 修复前后【逐位相同】**（⭐ 因为数组上电值 = 水位闸的读侧默认值）
> ⇒ ⛔ **拿"冷上电"当判据 = 假绿**。⭐ **真正的差异在【逻辑复位】**。

⭐ **操作**：先正常标定过一轮 ⇒ 按板载复位键 `AA13` ⇒ ⭐ 复位后**立刻**连发 `'N'`（在 `T` 之前）
🟢 复位后（`T` 之前）`'N'` ≈ **`1023`**；出 `T` 之后回到 **`0000`**
🔴 复位后 `'N'` **立刻 ≈ `0000`** ⇒ 沿用旧 `zero_r` = 修前形态

### T4 · ⭐ 阶段3：**片 1 的标定失败必须可见**

⭐ **操作**：⭐ **只按板 1**（板 2 同号键不动）⇒ 发 `'S'`
🟢 回 **`'1'`**（片1 err）或 **`'2'`**（两片）—— ⭐ **不可能一路 `.` 到 `D`**
🔴 ⭐ **一路回 `.`、最后 `D`**（看着"成功"）⇒ 片1 失败被吞
⚠️ 只接**一块**板时片1 `miso` 悬空 ⇒ **恒 `err`** ⇒ `'S'` **永远回 `'1'`**（⛔ 不是故障）

### T5 · ⭐ K-127：`raw` **按轴选片**（⭐ 激励—响应，⛔ 不依赖噪声阈值）

⭐ **操作**：标定**轴 8**（片1 的 ch0）时：

| 你做什么 | 🟢 绿 | 🔴 红 |
|---|---|---|
| ⭐ **故意抖片1 的轴 8** | 回包**跟着变** | ⭐ **完全无视片1** |
| ⭐ **反向对照：抖片0 的 ch0** | 回包**不变** | 回包**跟着变** |

### T6 · ⭐ `'P'` 探针：⭐ **现在按轴轮转，能诊断板 2 了**（⭐ 本版新能力）

> ⭐ **语义（⭐ 2026-10-01 已改，⛔ 与旧卡不同）**：`top.v:1780-1792`
> ⭐ **每次发 `'P'` ⇒ 探针轴 +1**（0→1→…→15→0）· ⭐ 用 `axis[3]` 选片（0~7=片0，8~15=片1）
> ⚠️ **回包格式未变**：`P` ＋ **5 位数字** ＋ `CRLF` = **8 字节**
> ⇒ 🔴 **回包里没有轴号！** ⇒ ⭐ **必须【数自己发了几次 `'P'`】** 才知道这个值属于哪一轴
> ⚠️ 而且它回的是 **`adc_farm` 的原始码**（≈2110 松手 / ≈2854 按下），⛔ **不是** `calib` 后的 `pos`

⭐ **操作**：
```powershell
# ⭐ 连发 16 次 ⇒ 依次得到 轴0..轴15 的原始码（⭐ 数次数！）
python tools\board_probe.py <COM口> --send "P,P,P,P,P,P,P,P,P,P,P,P,P,P,P,P"
```

| | ⭐ 观察 |
|---|---|
| **🟢 绿** | ⭐ **轴 8~15（板2）的值【跟着板2 的键动】**；⭐ 松手 ≈2110、按到底 ≈2854 |
| **🔴 红** | ⭐ **轴 8~15 的值恒 ≈2110 不变**（= 修前：恒读片 0 ⇒ 板2 的按键**被无视**） |

⚠️ ⭐ **本版已修**：⭐ 修前 `'P'` **永远只回片 0**，⭐ 按板2 的键会看到**板1 同号键（静止）的码**
⇒ 🔴 **会得出"板 2 按键没反应"的错误结论**（⭐ 比"看不到"更危险）⇒ ⭐ **这是本版要验的改进**。

### T7 · ⭐ 故障指示灯（⭐ 本版新增，⛔ 上卡没有）

⭐ **依据**：`top.v:4179-4203` —— `fault_sticky`（**sticky，只有复位才清**）⇒
`hb_div_eff = HEARTBEAT_DIV >> 3` ⇒ ⭐ **半周期 62.5 ms = 8 Hz 快闪**

| | ⭐ 观察 |
|---|---|
| **🟢 绿（正常）** | ⭐ 心跳灯 **≈ 1 Hz 慢闪**（⭐ 一直如此） |
| **🔴 红（有故障）** | ⭐ 心跳灯 **≈ 8 Hz 快闪** ⇒ ⭐ **`adc_farm` 或渲染超时出过错**，⭐ **复位才清** |

⚠️ ⭐ **判据**：⭐ **上电自检到弹琴全程，灯都不许变快闪**。
⭐ 若快闪 ⇒ ⭐ **记下"什么时刻开始快闪"**（⭐ 那是最有价值的现场证据）。

### T8 · ⭐ `span_sent_r2`：`err` 必须归属**本轴**（⛔ 不是上一轴的残值）

⭐ **操作**：① 让某轴**真失败一次**（中途松手）⇒ 看到 `1`
② ⭐ **立刻纠正**（两片该键按到底**保持住**）③ 看下次尝试的回包
🟢 纠正后**直接 `.`**　｜　🔴 ⭐ **还会再回一个 `1`**，**第三次**才 `.`
⇒ ⭐ **判据 = "失败 → 纠正 → 通过"之间多出的拒绝次数：修后 `0`、修前 `1`**
⚠️ 拒绝字节**总紧跟在轴号之后** ⇒ ⭐ `1` 与轴号 `1` **同形**，⭐ **按位置数**。

---

## 六、⭐⭐ 手感与声音（⭐ 用户最直接的判据）

| ⭐ | ⭐ 项 | 🟢 绿 | 🔴 红 |
|---|---|---|---|
| **1** | ⭐ **触发灵敏度（BATCH 2 的核心）** | ⭐ **轻轻一按就响**（⭐ 阈值 = **5.0%** 行程）；⭐ 松手干净 | 🔴 要按很深才响（⭐ 旧档 8.6%）／ 🔴 **一碰就响、松手还在响**（⭐ 阈值太松） |
| **2** | ⭐ **迟滞（2:1）** | ⭐ 阈值附近**不抖**（⭐ `205 → 102` 有滞回） | 🔴 在阈值附近**反复触发/断音** |
| **3** | ⭐ **力度跟行程（BATCH 4）** | ⭐ **按住继续下压 ⇒ 声音变大**（⭐ `POS_FULL=4095` 量纲对齐） | 🔴 力度**永远一样**／ 🔴 一按就满力度 |
| **4** | ⭐ **力度 vs 快慢** | ⭐ 快按 = 大声、慢按 = 小声 | 🔴 无关 |
| **5** | ⭐ **16 键音高** | ⭐ 每个键**各自的音**（键盘模式 = 钢琴 C3~C#4） | 🔴 所有键**同音**（⭐ 那是 2026-09-27 修掉的旧缺陷） |
| **6** | ⭐ **不挂音** | ⭐ 松开**正常衰减**；⭐ 多键同时按也各自收尾 | 🔴 松开后**一直响**／越按越多／越按越小 |
| **7** | ⭐ **鼓机** | ⭐ 发 `'B'` ⇒ **响、从强拍起**；发 `'D'` ⇒ **4 个节奏型可辨** | 🔴 发了 `'B'` 仍不响 |
| ⚠️ | ⭐ **不发 `'B'` 就不响** | ⭐ **这是设计如此**（源 B 上电静音）⇒ ⛔ **不是故障** | |
| **8** | ⭐ **looper / 曲谱** | ⭐ 录/播切换可用（`SCORE_UART_ENABLE=1`） | 🔴 不响应 |

⚠️ ⭐ **跑完 `'S'` 之后手感会变**（⭐ 一碰就触发 / 半按=满按）⇒ ⭐ **一次复位即恢复**（⛔ 别当故障）

---

## 七、⛔ 本版【听不到 / 看不到】的（⭐ 别以为是坏的）

| ⭐ | 现象 | 原因 |
|---|---|---|
| 🔴 | ⭐ **起始音（±八度）· 实时变调（−12..+12）· 串口 `'F'`/`'G'`** | 🔴 **本版 RTL 里【不存在】** —— ⭐ `N_CMD=13`（无 `F`/`G`）、`ui_base_semi`/`ui_base_commit` 是**无消费者的死线** ⇒ ⚠️ **`项目总介绍-20261001.md:103,104` 与 `视频脚本素材…:63` 声称已实现 ⇒ 那三处是【文档高报】** |
| ⭐ | **节拍器不响** | 本版源 B = **鼓机**（`SEL_DRUM=1`）⇒ 节拍器被综合扫掉 |
| ⭐ | **鼓机自己响** | ⭐ **源 B 上电静音** ⇒ **要发 `'B'`** |
| 🔴 | **颤音 / 右手推子** | `RIGHT_ADC_ENABLE = 0` |
| 🔴 | **`'Q'` 诊断包 / `probe_q.py`** | `DPOS_DIAG = 0`（⭐ 要它得改 **1** 并**重跑 PnR**） |
| ⚠️ | **`o` / `b` / `?` 三个拒绝码** | ⭐ **上板造不出**（`adc_farm` 恒产帧；`err=0` 必伴随 `busy=1`） |
| ⚠️ | **右手板 B（OLED/4 按键/EC11）** | 🔴 **引脚已被主动撤回**（⭐ 待硬件决定，⭐ 见 T3 复核 §七） |
| ⚠️ | **`'P'` 回包里没有轴号** | ⭐ 格式未变（⭐ 免得与 ESP32 侧协调）⇒ ⭐ **靠"数请求次数"** |
| 🔴 | **`XKEY` 跨键检测** | 🔴 **main 里从未并入**（⭐ `step/B-timing`）⇒ ⭐ 本版没有 |

---

## 八、⭐ 记录表（⭐ 每测一项就填，⛔ 别凭记忆）

| ✅ | ⭐ 项 | ⭐ 判据 | 实测 | 判定 |
|---|---|---|---|---|
| ☐ | `.fs` sha256 | `B0C094D7…76E50` | | |
| ☐ | **T0** `t`→`T` | 🟢 ≈7 ms ／ 🔴 ≈0.5 ms 或 ≈8 s | | |
| ☐ | **T0b** `T` 后 16×`'N'` | 🟢 全 `0000` ／ 🔴 全 `1023` | | |
| ☐ | **§四①** 键 **14/15** 出声 | 🟢 出声 ／ 🔴 无声 | | |
| ☐ | **§四①** 16 键全出声 | 🟢 16/16 | | |
| ☐ | **§四②** 和弦后**第一下** | 🟢 立刻响 ／ 🔴 不响（**记下第几下才响**） | | |
| ☐ | **§四②** 是否"按序继承" | 🟢 否 ／ 🔴 是 | | |
| ☐ | **§四②** 挂音 | 🟢 无 ／ 🔴 有 | | |
| ☐ | **T1** 失败 `'S'` 后满按 | 🟢 仍 `4095` ／ 🔴 掉 `0744` | | |
| ☐ | **T2** 上电/复位 200 ms 内 `'S'` | 🟢 `!`…`T`…`s` ／ 🔴 开头就 `s` | | |
| ☐ | **T3** 复位后 `'N'`（`T` 前） | 🟢 `1023` ／ 🔴 `0000` | | |
| ☐ | **T4** 只按板1 跑 `'S'` | 🟢 `1`/`2` ／ 🔴 一路 `.` 到 `D` | | |
| ☐ | **T5** 抖片1 / 抖片0 | 🟢 跟片1 动 ／ 🔴 跟片0 动 | | |
| ☐ | **T6** 16×`'P'` 板2 的键 | 🟢 轴8~15 跟着动 ／ 🔴 恒 2110 | | |
| ☐ | **T7** 心跳灯 | 🟢 全程 ≈1 Hz ／ 🔴 出现 8 Hz 快闪 | | |
| ☐ | **T8** 失败→纠正→通过 | 🟢 直接 `.` ／ 🔴 多一个 `1` | | |
| ☐ | **§六1** 轻按就响 | 🟢 5% 就响 ／ 🔴 要按很深 | | |
| ☐ | **§六3** 力度跟行程 | 🟢 继续下压变大 ／ 🔴 不变 | | |
| ☐ | **§六5** 16 键音高 | 🟢 各自不同 ／ 🔴 全同 | | |
| ☐ | **§六7** 鼓机 `'B'` / `'D'` | 🟢 响 + 4 型可辨 | | |
| ☐ | **§六8** looper | 🟢 录/播可用 | | |

---

## 九、⚠️ 两条操作铁律（⛔ 违反会得出错结论）

| # | ⭐ 铁律 | ⭐ 为什么 |
|---|---|---|
| **1** | ⭐ **每轮 `'S'` 之前必须先发 `'X'`** | ⭐ `'S'` **只在 `S_IDLE` 被响应** ⇒ 上一轮没结束时报 `s` 但**什么都不做**（⭐ 看着受理、实际不动） |
| **2** | ⭐ **`'D'` 是粘滞的** ⇒ **第二轮不会再有 `D`** | ⭐ 所以每轮先 `'X'`，⛔ **别等第二个 `D`** |

⭐ **串口**：⭐ **`J9` 排针 · 500000 baud · 8N1 · ⛔ 无流控**
（⭐ `USB-TTL TX → J9 N26` · `RX → J9 N25` · `GND → J9 GND`；⛔ **板载 USB-C 走不通**）

---

## 十、⭐ 证据来源（⭐ 全部核到代码，⛔ 无转述）

| 内容 | 来源 |
|---|---|
| AU 与 HEAD 的 `rtl/` 一致性 | `git diff --stat f682fe3 HEAD -- rtl/ constr/` = 空 |
| 时序 / 资源 | `build/bitstreams/AU_main_declfix_B0C094D.timing.txt` · `.rsc.xml` |
| 阈值量纲 | `rtl/top.v:2283`（`EVT_TRIG_TH=205`）· `:2284`（`EVT_REL_TH=102`）· `:2295`（`CALIB_FULL=4095`）· `:2895`（`.POS_FULL(CALIB_FULL)`） |
| `STILL_TOL=48`（旧卡 R1 已消除） | `rtl/top.v:1646` · `:1654-1655` |
| 池按来源（键 14/15） | `rtl/w3b/note_manager.v:509` · `:523` · `:1246` |
| `'P'` 按轴轮转 | `rtl/top.v:1770-1798`（`pp_axis_r` · `pp_raw_sel` · `.ch_i`） |
| `adc_farm` 片1 保持 | `rtl/drivers/adc_farm.sv:145-175` · `:190-191` |
| 故障指示灯 | `rtl/top.v:1416`（`fault_any_w`）· `:4179-4203`（`fault_sticky` · `hb_div_eff`） |
| 上板未解释症状 | `tb/e2e/tb_demo_stall_diag.sv:9-14` |
| 编译期开关 | `rtl/top.v:120` · `:161` · `:185` · `:277` · `:1507` · `:2340` · `:3070` |
| 变调不存在（文档高报） | `rtl/w3a/calib_cmd.v:366`（`N_CMD=13`）· `rtl/top.v:702-703,736,738`（死线） |
| 串口在 `J9` 排针 | `constr/top.cst:331-367` |
