hokuu1102/Gowin2026-PolySynth/bringup/21-上板验证卡-AV-量纲返工复验-20261001.md

# ⭐⭐ 上板复验卡 · **AV**（量纲返工后）· 2026-10-01

> ⭐ **要回答的唯一问题**：⭐ **你报的 4 条回归，消失了没有？**（⭐ 以及已修好的 2 条有没有丢）
> **前一版（AU）的卡**：`bringup/20-上板验证卡-AU-20261001.md` —— ⭐ **它的 T1~T8 判据、串口接法、操作铁律【本版仍然适用】** ✅
> **根因与修复记录**：`files/00-总览/量纲返工根因与修复-20261001.md`

---

## 〇、烧哪个

| ⭐ | ⭐ 项 | ⭐ 值 |
|---|---|---|
| **文件** | ⭐ **`C:\Users\hokuu\Desktop\FPGA\FPGA2026\build\bitstreams\AV_main_scale_revert_6FE43A96.fs`** | |
| **sha256** | `6FE43A96247C401B70CCA2E67D4A9EB919995F1106F576DA4B57BE7DC3C8804A` | |
| **大小** | `18,528 KB` | |
| **时序** | ⭐ **`0 setup / 0 hold`** · ⭐ **`Fmax = 57.114 MHz`**（⭐ **+14.23%**）⇒ ⭐ 远超 3% 门槛（51.5 MHz）✅ | |
| ⭐ **门序** | ⭐ **四道门全绿** ✅ —— ① 综合门 **0 ERROR** / 50 Compiling · ② 聚焦 tb 全过（`vel` 6/6 · `param_extract` 1/1 · `looper_tail` 1/1 · `e2e` 1/1 · `event_extract` 1/1）· ③ PnR **`0 setup / 0 hold`** · **`Fmax = 57.114 MHz`** · ④ 全量回归 ⭐ **`passed 108 / total 108`**（8.6 min） |
| ⭐ **资源** | `Register 15649` · `Lut 36118` · `Bsram 27`（⭐ 对比 AU：`15650 / 35752 / 27` ⇒ ⭐ `Lut +366`，⭐ 与"改了 4 个比较常量"相符 ✅） |
| ⭐ **归档校验** | ⭐ `sim/archive_bitstream.ps1 -CompareTo AU_main_declfix_B0C094D` ⇒ ⭐ **`fs` / `timing.txt` / `rsc.xml` 三件全部 `differs`** ✅（⭐ 防"手工拷贝留下陈旧文件"—— `K-164` 的教训） | |
| ⭐ **相对 AU 改了什么** | ⭐ 只改**一组量纲**（4 个常量）＋ 1 个 tb 镜像 ＋ 1 处过时注释 ⇒ ⭐ **`BATCH 3`（键 14/15）· `8.1/8.2/8.3` · `.sdc` 修复 · declfix 全部保留** ✅ | |

⚠️ 烧之前建议先 `Get-FileHash` 核对上面那串 sha256（⭐ 本卡的指纹就是它）。

---

## 一、⭐⭐⭐ 必验：你报的 4 条回归

| ⭐ | ⭐ 症状（AU 上你实测） | ⭐ 本版应该 | ⭐ 怎么验（⭐ 靠听，⛔ 不用仪器） |
|---|---|---|---|
| **①** | 🔴 **力度跟随消失** | ⭐ **按住后继续下压 ⇒ 声音明显变大** | ⭐ 按一个键到底**停住**，然后**继续慢慢加力** ⇒ ⭐ 音量应**跟着涨** |
| **②** | 🔴 **总音量变小** | ⭐ **恢复到 AM 那一版的响度** | ⭐ 与 `AM` 对比（⭐ 若你手边还有 AM 位流就更好）；⭐ 或直接比"按到底的最大声" |
| **③** | 🔴 **更不灵敏（要按很多才触发）** | ⭐ **轻按就触发**（⭐ 行程 **8.6%**，与 `AM/AN` 之前的 `64` 一致） | ⭐ 极轻按一下 ⇒ 应出声；⭐ 松手干净 |
| **④** | 🔴 **尾音变短、区分度丢失** | ⭐ **尾音恢复**（⭐ BASS ≈156 ms · GUITAR ≈402 ms）＋ ⭐ **音色之间有区分度** | ⭐ 切 4 个音色各按一下 ⇒ ⭐ **尾音长短应听得出差别** |

⭐ **根因对应**（⭐ 一句话）：① 是"力度阈跑到行程外"（`VEL_T2_EFF=3276 > 744`）；② 是"斜率把力度上限压到 98"；③ 是"阈值按 4095 档算、而板上是 744 档"；④ 是"②的连带（包络峰值 ∝ 力度）"。

---

## 二、⭐⭐ 版本指纹：**不用手感就能确认烧对了**

⭐ 返工后 `pos` 是 **744 档**（⛔ 不是归一档 4095）⇒ ⭐ 满按时的 `'N'` 读数**直接暴露版本**：

```powershell
# ⭐ 一个键【按到底停住】⇒ 连发 16 次 'N' ⇒ 看那一轴的值
python tools\board_probe.py COM32 --send "N,N,N,N,N,N,N,N,N,N,N,N,N,N,N,N"
```

| ⭐ 满按读到 | ⭐ 说明 |
|---|---|
| ⭐ **≈ `00744`** | ✅ **AV 的新量纲**（行程档）⇒ ⭐ 烧对了 ✅ |
| 🔴 **≈ `04095`** | ⚠️ **还是 AU/AP 那一档** ⇒ ⭐ **烧错了 / 没烧上** |
| ⭐ 松手读 **`00000`** | ✅ 零点正常（⭐ 与 T0b 同一手法） |

⭐ 顺带这一条同时验证了 **`POS_FULL` 的来源修好了**（⭐ 这正是本轮返工的第 3 个改动）✅

---

## 三、⭐ 必须【保持】的两条（⛔ 别被回归带走）

| ⭐ | ⭐ 项 | ⭐ 期望 |
|---|---|---|
| **1** | ⭐ **键 14/15（G#3/A#3）出声** | ⭐ **仍正常出声** —— ⭐ 这是 `BATCH 3` 的成果，⭐ 本版**保留**了它 ✅ |
| **2** | ⭐ **上电后第一下按键就出声** | ⭐ 仍立刻出声（⭐ 修A 的冷启动，⭐ 保留 ✅） |

⚠️ 若这两条**坏了** ⇒ ⭐ 说明返工**误伤了**别的东西 ⇒ ⭐ **立刻告诉我**（⭐ 我会回退那一处再查）。

---

## 四、⭐ 本版编译期参数（⭐ 与 AU 的差别一目了然）

| ⭐ 常量 | ⭐ AU（你测出 4 条回归的那版） | ⭐ **AV（本版）** |
|---|---|---|
| `EVT_TRIG_TH` | 205（⭐ 744 档 = **27.6%**，太深） | ⭐ **64**（**8.6%**） |
| `EVT_REL_TH` | 102 | ⭐ **32**（4.3%，迟滞仍 2:1） |
| `POS_FULL` 的来源 | `CALIB_FULL`（归一档 **4095**）🔴 | ⭐ **`TRAVEL_TARE`（行程档 744）** |
| `pos_to_vel` 斜率 | ×48（🔴 满行程只到 98） | ⭐ **×263**（744 ⇒ 恰好 255） |
| `STILL_TOL` | 48 | ⭐ 48（⭐ 不动） |
| `SEL_DRUM` / `DPOS_DIAG` / `RIGHT_ADC_ENABLE` | 1 / 0 / 0 | ⭐ 不变 |

⭐ **新增 2 条自检**（⭐ 只在仿真里打印，⛔ 综合期被忽略 —— ⚠️ 见 §八 待办）：
`TRAVEL_TARE > 1023` · `TRAVEL_TARE == CALIB_FULL` ⇒ ⭐ 就是为了让"**这次的错**"下次能被抓到。

---

## 五、⛔ 本版仍然【没有】的（⭐ 别以为是坏的）

| ⭐ | 现象 | 原因 |
|---|---|---|
| 🔴 | **起始音 ±八度 · 实时变调 · 串口 `'F'`/`'G'`** | ⭐ **RTL 里不存在**（⭐ 见 `T3-复核-总合成-20261001.md` §六：3 处对外文档高报） |
| ⭐ | 节拍器不响（源 B = 鼓机）· 鼓机要发 `'B'` 才响 | 同 AU（⭐ 设计如此） |
| 🔴 | 颤音 / 右手推子 · `'Q'` 诊断包 | `RIGHT_ADC_ENABLE=0` · `DPOS_DIAG=0` |
| ⚠️ | 右手板 B（OLED/4 键/EC11） | 引脚已撤回（⭐ 待硬件决定） |
| 🔴 | `XKEY` 跨键检测 | ⭐ main 从未并入 |

---

## 六、⭐ 沿用 AU 卡（⛔ 不重复列）

⭐ 以下**判据与操作**在 `bringup/20-上板验证卡-AU-20261001.md` 里已写全，**本版全部适用**：
- ⭐ **T1** 水位闸：一次失败的 `'S'` 不得毁掉已标定的归一化
- ⭐ **T3** 复位后 `'N'` 应为"未标定"态
- ⭐ **T4** 片 1 的标定失败必须可见
- ⭐ **T5** `raw` 按轴选片（抖片1 跟动 / 抖片0 不动）
- ⭐ **T6** `'P'` 探针按轴**轮转**（16 次一轮覆盖两片；⚠️ 回包里**没有轴号**，⭐ 要数次数）
- ⭐ **T7** 故障指示灯（⭐ 全程应 **≈1 Hz 慢闪**；🔴 出现 **≈8 Hz 快闪** = 出过错，⭐ 记下何时开始）
- ⭐ **T8** `err` 归属本轴
- ⭐ **串口**：⭐ `J9` 排针 · `TX→N26` / `RX→N25` / `GND` · **500000 8N1 无流控**（⛔ 板载 USB-C 走不通）
- ⭐ **两条操作铁律**：⭐ 每轮 `'S'` 前先发 `'X'` · ⭐ `'D'` 是粘滞的（第二轮不会有）
- ⚠️ ⭐ **T0 判据已作废**（时间分辨率不够）⇒ ⭐ **改用语义判据 `T0b`**（⭐ 见 AU 卡 §三）

---

## 七、⭐ 记录表（⭐ 每测一项就填）

| ✅ | ⭐ 项 | ⭐ 判据 | 实测 | 判定 |
|---|---|---|---|---|
| ☐ | `.fs` sha256 | `6FE43A96…C8804A` | | |
| ☐ | ⭐ **版本指纹** 满按 `'N'` | 🟢 ≈**00744** ／ 🔴 ≈04095（烧错了） | | |
| ☐ | ⭐ **① 力度跟随** | 🟢 继续下压音量涨 ／ 🔴 不变 | | |
| ☐ | ⭐ **② 总音量** | 🟢 恢复到 AM 的响度 ／ 🔴 仍偏小 | | |
| ☐ | ⭐ **③ 触发灵敏度** | 🟢 轻按就触发（8.6%）／ 🔴 要按 1/4 | | |
| ☐ | ⭐ **④ 尾音** | 🟢 恢复＋4 音色可辨 ／ 🔴 仍短/无区分 | | |
| ☐ | ⭐ 保持：键 **14/15** | 🟢 出声 ／ 🔴 无声（⭐ 立刻报我） | | |
| ☐ | ⭐ 保持：**第一下就响** | 🟢 立刻 ／ 🔴 要按十几下 | | |
| ☐ | 16 键音高 | 🟢 各自不同 ／ 🔴 全同 | | |
| ☐ | 挂音 | 🟢 松手正常衰减 ／ 🔴 一直响 | | |
| ☐ | 鼓机 `'B'` / `'D'` | 🟢 响 ＋ 4 型可辨 | | |
| ☐ | 心跳灯 | 🟢 全程 ≈1 Hz ／ 🔴 出现快闪 | | |

---

## 八、⚠️ 已知未修 / 待办（⭐ 本版**故意**没做）

| ⭐ | ⭐ 事项 |
|---|---|
| **1** | 🔴 ⭐ **那 2 条新自检还不是"能红"的判据** —— ⭐ `$display` 在综合期**被忽略**（`EX3858`），⭐ 且**没有 tb 断言它** ⇒ ⚠️ 目前只是"打印一行"。⭐ 改法：⭐ 让例化真 `top` 的 tb **断言**它（⭐ 这样把 `TRAVEL_TARE` 填错时**测试会 FAIL**）✅ |
| **2** | 🔴 ⭐ **回归盲区**：`tb/w3a/tb_param_extract.sv:41` 的 `POS_FULL` 镜像**没跟 RTL** ⇒ ⭐ **没有任何 tb 验证"顶层传下去的 `POS_FULL` 对不对"** ⇒ ⭐ 建议补一条"集成值"判据（⭐ `C117` 收录了这条教训） |
| **3** | ⭐ **`'P'` 回包不含轴号** ⇒ ⭐ 靠"数请求次数"（⭐ 见 §六 T6） |
| **4** | ⭐ 全量变异测试**被中途停掉**（停在 `top` 组 `M39`）⇒ ⚠️ 待重跑（⭐ 本轮改动作废了 `top` 组的结论） |
| **5** | ⭐ `calib` 的 `'S'` 标定：⭐ **本版不再依赖它**（⭐ 用户裁定放弃 span）⇒ ⚠️ 若将**换板/改定位板高度** ⇒ ⭐ **4 个数要一起重算**（⭐ 公式见 `top.v` 注释） |
