hokuu1102/Gowin2026-PolySynth/bringup/12-上板验证卡-K132-20260925.md

# ⭐ 上板验证卡 · `K-132` 修复后（2026-09-25）

> **目的**：⭐ 验证 `'S'` **是否恢复回轴号**
> **前提**：⭐ 需要**重新烧 bitstream**（⭐ RTL 改了 ⇒ ⚠️ 必须重跑 PnR）
> **判据**：⭐ 见 §三 —— ⭐ **一眼可辨**，⛔ 不用含糊猜测

---

## 一、⭐ 先跑 PnR 出 bitstream

```powershell
cd C:\Users\hokuu\Desktop\FPGA\FPGA2026
powershell -NoProfile -ExecutionPolicy Bypass -File sim\gowin_build.ps1
#   ⭐ 约 10 分钟 · ⭐ 判据：exit 0 + 0 setup / 0 hold
#   ⇒ ⭐ bitstream: impl/pnr/Gowin2026.fs
```
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
