hokuu1102/Gowin2026-PolySynth/sim/evidence/test_mode_n8_spectrum.png

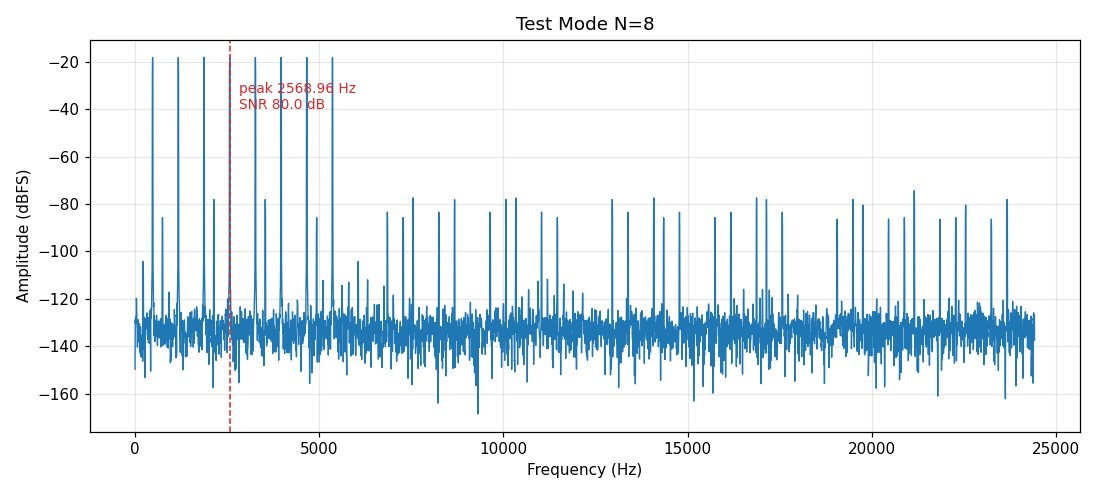
sim/evidence/test_mode_n8_spectrum.png
