hokuu1102/Gowin2026-PolySynth/docs/hmi-screen-repair-20261103.md

# 串口屏配套修订与验收记录

日期：2026-11-03。基于 51 线的源码提交 `d3420c54bd82cc99547b70a4c784af99b88bb31b`。

本轮交付为 FPGA 源码和 HMI 源工程。未生成 FPGA `.fs`、屏幕 `.TFT`，未执行新的综合、布局布线或时序验收，未推送远端。板上已有码流不会因本地源码修改而变化。

## 已落实的修改

1. 将诊断发送 FIFO 的地址宽度从写死的 3 位改成随深度变化，顶层深度改为 64。保留默认深度 8 的模块兼容性。新增深度 8/64 的满空、绕回、溢出和清除测试，原实现的深度 64 用例已先失败。
2. 保留屏幕回显直连 UART 的所有权和背压规则。该路径绕过诊断 FIFO，不能将本版长帧现象直接归因于 FIFO 只有 8 字节。修正了相应过时注释。
3. 增加页面通知 `71 06 <page> FF FF FF`，page 只能为 0 或 1。页面后初始化发送通知，再发送原有 `88 FF FF FF`。FPGA 只回显已加载页面的私有控件，切页时重新刷新该页。
4. FPGA 按实际 `ui_fx_mask[2:0]` 回写 Program.s 的 `fx0/fx1/fx2`，并更新当前页的效果器灯、文字或头部颜色。保留屏端按钮逻辑与 `71 19` XOR 命令。没有页面通知的旧屏工程继续使用旧的 58 个状态字段刷新协议。
5. 进入 page0 时幂等退出 EC11 参数模式并恢复原 BPM/变调对象；重复通知不会重新进入参数模式。保留旧的 raw `p` 切换、`o+n` 选择及屏幕数值载荷隔离。
6. Loop 背景色改为录音 51461、回放 7142、武装 56224，空闲色保持原值。`t_lock` 改为“锁定／实时生效”，仍取当前档真实 hold 位；保留 `t_lock_info` 对音高、音量两档的独立锁定汇总。
7. 增加可查询的 HMI 发送诊断计数，含起帧、物理完成帧、已接受字节、非法启动以及 FIFO 溢出/丢弃。诊断回复单独取得 UART 所有权，不插入屏幕帧内部。
8. 在 HMI 副本中将 `t_slide` 字体由 9 改为 UTF-8 字体 4（18 像素），宽度从 232 改为 128，保留位置 `(254,216)` 和高度 48，初值改为完整“关闭 (GLIDE OFF)”。编辑器预览确认文字完整显示、刷新区域避开滑音灯和按钮。
9. 将 `b_uplink.y` 从 240 改为 252，使其避开 `t_kd` 的 y=207、高度 40 区域，保留触摸事件。将 `b_vv_hdr.pco/pco2` 均改为 0，匹配音量颤音黑字要求。

## HMI 核对结果

使用现有 USART HMI 1.68.1，在工作副本中编辑并通过原生保存操作写回，原附件未修改。型号为 `TJC1060X570_011`，1024×600，UTF-8，115200，recmod=0。

有效 Program.s 声明 `int fx0=0,fx1=0,fx2=0`，没有 va0/va1/va2 初始化。原两页前初始化中的记忆恢复逻辑保留，新增通知放在后初始化，确保控件已加载。

六个参数按钮的有效弹起事件已在编辑器逐项查看：

| 控件 | 参数 | 发送 HEX，尾部均为 FF FF FF |
|---|---|---|
| b0 | 增益 | 6F 00 |
| b1 | 补偿 | 6F 01 |
| b2 | 合唱长度 | 6F 07 |
| b3 | 干湿比 | 6F 02 |
| b4 | 延迟长度 | 6F 06 |
| b5 | 延迟反馈 | 6F 03 |

两个颤音头部的有效事件已在编辑器核对：彩色分支分别只发送 `71 05 01`、`71 05 02`，灰色分支只改变自身 bco；不存在互相设灰或发送 `71 05 00`。

`b_back` 原事件只有 `page page0`，现由 page0 后初始化通知完成 FPGA 退出动作。`b_uplink` 保留 `65 00 0F FF FF FF`，未勾选自动发送键值，避免重复触发。

效果器头部保持私有作用域。跨页写私有控件会失败，因此使用页面通知后只刷新当前页；这也符合[厂商对跨页操作作用域的说明](https://www.tjc1688.com/contents/25/465.html)。

配套 HMI 为 `hmi7/p0-repaired-20261103.HMI`，SHA256：`71ede99a1853e2919ddc0f8a2d4d0327d24cf74ba939b7ed692d2f9692c2b837`。
原附件 SHA256：`b8fabe5ab8230d55211999ecc89c820647156c8c8d0b791d8220432c7f04fbc6`，修改前后相同。

## 发送计数的实机读取方法

此方法只适用于将本轮源码生成并烧入 FPGA 后。旧码流不包含此接口。

1. 将串口助手接到板载主 UART，设为 115200、8N1、HEX 发送；先避免上位机或屏幕同时驱动板载 RX。
2. 发送 `71 07 00 FF FF FF`。
3. FPGA 在当前完整包结束后回复一行 30 字节 ASCII：`HMI ` + 24 位大写十六进制数字 + CR LF。

24 位数字连续排列为 `SSSSCCCCBBBBBBBBEEEEDDFF`：

| 字段 | 含义 |
|---|---|
| SSSS | 起帧计数，16 位 |
| CCCC | 最后一个 FF 的 UART 发送完成后才增加的完整帧计数，16 位 |
| BBBBBBBB | HMI 被 UART 接受的字节数，32 位 |
| EEEE | 无所有权或 UART 忙时仍启动的次数，16 位，正常应为 0000 |
| DD | 原 FIFO 饱和丢弃计数，8 位 |
| FF | bit0 为 FIFO sticky overflow，其他位为 0 |

起帧、完成帧、字节、非法启动计数按位宽回绕，复位清零；FIFO 的丢弃计数沿用原来的饱和/清除规则。查询期间计数先快照再发送。正常操作不会自动发送这条诊断回复。

要定位长帧现象，应同时抓取 FPGA TX 的原始 HEX，包含 `t_mode/t_slide/t_kd/b_uplink` 的完整内容和三个 FF。只看到帧头或生成端日志不足以证明屏幕已收到整帧。

## 回归结果与边界

18 项选定运行通过，详细结果见配套 `targeted-tests.json` 和日志。未执行全量回归。

| 范围 | 结果 |
|---|---|
| uart_ui 原回归 | 425 项检查通过，含整帧字节与颜色 |
| 显示专项 | 65 项检查通过，含独立锁定汇总、三种 HDMI 文案及帧快照 |
| 页面同步 | 9 项检查通过；旧实现对应场景先失败 |
| FIFO | 默认队列、清除/丢弃并发、50412 周期参考等价、8/64 深度测试通过 |
| 诊断模块 | 物理完成时刻、非法启动、快照、所有权和背压通过 |
| 真实主 UART 分频 434 | 前 10 帧、283 字节逐字节核对通过，最长 44 字节 |
| 加速 UART 分频 4 | 完整刷新、刷新重入、参数写入、EC11 状态回包及计数查询竞争通过；117 个屏幕帧，最长 50 字节 |
| EC11 顶层 | 真实 UART、实际 EC11 步进、重复参数选择、page0 幂等退出、原对象恢复通过 |
| Loop 顶层 | 踏板/屏幕/UART 录停、真实 bar_start 对齐、录入与回放、清空、鼓机关后录制和 REC 状态回显通过 |
| Loop 组件 | 小节对齐、鼓不进 Loop、回放保持录制音色与松键尾音通过 |
| 既有控制行为 | 四节奏型循环、实体 key15 回传切换、关闭后拒绝新上行事件通过 |

顶层专项使用测试专用 HDMI 常量输出替身以节省仿真时间，真实 UART、UI、仲裁、EC11、beat_gen 和 looper 均保留。该替身不进入 FPGA 工程，不构成 HDMI 像素或物理输出验收。Loop 专项仅缩小 beat_gen 的 PPQN 和 play_seq 默认相位增量，刺激采集事件边界；没有强制 bar_start 或 looper 状态。

复跑示例，在仓库根目录执行：

```powershell
python tools/run_hmi_repair_tests.py tb_uart_ui final
python tools/run_hmi_repair_tests.py tb_uart_ui_page_sync final
python tools/run_hmi_repair_tests.py tb_top_hmi_long_frames fast
python tools/run_hmi_repair_tests.py tb_top_hmi_long_frames real115200
python tools/run_hmi_repair_tests.py tb_top_looper_record_start final
```

默认输出位于 `D:/ChatGPT/Outputs/FPGA-screen-integration-repair-20261102`，可用环境变量 `FPGA_TEST_OUT` 覆盖。

静态检查 7/7 通过；选定编译日志无 Pruning 或 implicit definition。文档引用检查无硬错误。姓名检查因缺少 names.local.txt 跳过，不计为通过。

## 必须保留的待验收项

- FPGA 单独复位后，需在新 HMI 中切页或重新进入当前页面，发送完整页面通知与握手以恢复页面识别；旧式裸 88 仅保持兼容刷新，不携带当前页信息。自动跨页重连尚未实机验证。
- 本轮仿真未复现实机“长帧发不全”，因此不将 FIFO 扩容或显示修订宣传为 R10 根因修复。仍需烧录配套版本后抓取实际 TX，结合计数闭环。
- “武装中不开始录音”在当前受控顶层测试中没有复现。本轮未修改录音状态机，也未覆盖所有真实 BPM、按键时机和接线组合，仍需实机验证。
- HMI 已原生保存并重新打开核对，不等同于新 TFT 编译及屏端运行验收；未运行会产生 TFT 的编译/调试步骤。
- 新源码尚无综合资源和时序结果，不能沿用旧码流的 50MHz/Fmax 数字作为本轮结论。
- 需要后续明确要求统一生成 FPGA 与屏幕烧录件后，再做配套编译、50MHz 时序门禁和上板验收。
