hokuu1102/Gowin2026-PolySynth/hmi7/history/串口屏v3-远端快照-aa1162f.md

# 🖥️ 串口屏 v3 搭建清单 · TJC X2 7寸 1024×600（最终版）

> **屏**：淘晶驰 TJC X2，7 寸，1024×600，接 **FPGA 板载 UART**
> **上位机**：USART HMI（TJC 版）
> **日期**：2026-10-29（丙）· 本版 = v2 修订版的**干净终版**，可直接照做
> **配套 RTL**：`rtl/w3c/uart_ui.v`（回显 FSM **48 字段全动态**：page0 22 + 心跳 1 + page1 25；
> 三件套 0x88 全量重发 / 0x19 翻转 / 0x1B 八度循环 + **§八收口三件**：t_loop 三态配色 /
> led_* 状态灯 / page1 动态字段，tb **312 checks PASS**，2026-10-29 深夜收口；
> **2026-10-30 补**：⭐ 触摸控件 3 = 音色循环（b_timbre，屏上切音色闭环）⇒ tb 317 checks PASS）
> **2026-10-31 补**：⭐⭐ **page0 控制面板化**：触摸控件 4..14 = 滑音/鼓机/打鼓/移调±/循环录播清/档位/BPM±
> （11 个新热区按钮，全部真控 FPGA 寄存器 + 回显自动闭环）⇒ tb **340 checks PASS**。
> **历史**：12 处修正过程见 `串口屏v2-修订版-20261029.md`（本文件不再重复）

---

## 一、⭐ 建工程（第一步）

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

> ⭐ 页面背景色：page0 / page1 属性里设 **63454**（#F0F3F6 浅灰底）。

---

## 二、⭐ 字库（6 档，字体选粗）

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

---

## 三、Page 0：演奏与综合控制看板

### 0. 底板（⭐ 最先建，白色卡片底）

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

### 1. 顶栏与系统状态（y: 0..40）

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

### 2. 卡片 A：演奏核心区

| 控件名 | 类型 | 坐标 | 默认内容 | 前景/背景 | 字库 | 说明 |
|---|---|---|---|---|---|---|
| `l_card_a` | 文本 | (32, 58, 300, 20) | `CORE PERFORMANCE / 演奏核心` | 22477 / 透明 | ① | 静态 |
| `t_timbre` | 文本 | (32, 86, 210, 48) | `BASS` | 9509 / 63455 | ⑤ | FPGA 回显：BASS/GUITAR/PIANO/PAD |
| 🔥 `b_timbre` | **按钮** | (168, 94, 70, 36) | `切音色` | 2459 / 65535 | ② | **叠放在 t_timbre 右端上层**（主用，同 b_mode 做法），事件见 §六 · ⭐ 2026-10-30 落地。**点完后 t_timbre 大字自动同步变**：FPGA 回显帧驱动，屏不用记账（⚠️ 需重出位流才在板上生效；模拟器单机只出 HEX 不变字，属正常） |
| ⭐ `h_timbre`（可选） | **热区** | (32, 86, 210, 48) | （透明，无内容） | — | — | 可选增强：盖住整个 t_timbre，点 BASS 大字**任意处**也可切（与 b_timbre 发同一帧，二选一或并存均可；并存时热区后建于按钮之后即接管触摸；热区后建才在上层） |
| `t_mode` | 文本 | (254, 86, 232, 48) | `指板模式 [FRET]` | 2459 / 63455 | ③ | FPGA 回显 |
| 🔴 `b_mode` | **按钮** | (400, 94, 80, 36) | `切换` | 2459 / 65535 | ② | **叠放在 t_mode 右端上层**，触控翻转模式，事件见 §六 |
| `t_base` | 🔴 **文本** | (32, 144, 454, 48) | `基准音: C4 (最低音 C3)` | 9509 / 63455 | ③ | FPGA 回显，**纯显示不可点** |
| `b_oct` | 🔴 **按钮** | (374, 150, 108, 36) | `点击切八度 ↕` | 2459 / 65535 | ② | **叠放在 t_base 右端上层**，事件见 §六 |
| `t_trans` | 文本 | (32, 202, 210, 52) | `0 SEMI (原调)` | 55264 / 63455 | ③ | FPGA 回显，−12~+12 |
| 🔥 `b_tr_dn` | **按钮** | (110, 210, 60, 36) | `-1` | 2459 / 65535 | ② | 叠放在 t_trans 右端上层，移调 −1 半音（控件 8，⭐ 2026-10-31；⚠️ 文案用 ASCII 减号，⛔ 不用 U+2212，字库没有） |
| 🔥 `b_tr_up` | **按钮** | (176, 210, 60, 36) | `+1` | 2459 / 65535 | ② | 叠放在 t_trans 右端上层，移调 +1 半音（控件 7，⭐ 2026-10-31） |
| `t_slide` | 文本 | (254, 202, 232, 52) | `开启 (GLIDE ON)` | 6822 / 63455 | ③ | FPGA 回显 |
| 🔥 `b_slide` | **按钮** | (410, 210, 68, 36) | `滑音` | 2459 / 65535 | ② | 叠放在 t_slide 右端上层，滑音开/关（控件 4，⭐ 2026-10-31） |

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

### 3. 卡片 B：节奏与循环区

| 控件名 | 类型 | 坐标 | 默认内容 | 前景/背景 | 字库 | 说明 |
|---|---|---|---|---|---|---|
| `l_card_b` | 文本 | (540, 58, 360, 20) | `RHYTHM & LOOPER / 节奏循环 (无节拍器)` | 22477 / 透明 | ① | 静态 |
| `t_bpm` | 文本 | (540, 86, 180, 66) | `120` | 9509 / 63455 | ⑥ | FPGA 回显，48px 巨字 |
| 🔥 `b_bpm_dn` | **按钮** | (552, 104, 56, 36) | `-5` | 2459 / 65535 | ② | 叠放在 t_bpm 左端上层，BPM −5（控件 14，40 下限，⭐ 2026-10-31；⚠️ 文案用 ASCII 减号） |
| 🔥 `b_bpm_up` | **按钮** | (652, 104, 56, 36) | `+5` | 2459 / 65535 | ② | 叠放在 t_bpm 右端上层，BPM +5（控件 13，240 上限，⭐ 2026-10-31） |
| `t_drum` | 文本 | (732, 86, 260, 66) | `开 II [PATTERN II]` | 2459 / 63455 | ④ | FPGA 回显，严格罗马数字 |
| 🔥 `b_drum` | **按钮** | (920, 102, 64, 40) | `节奏` | 2459 / 65535 | ② | 叠放在 t_drum 右端上层，节奏型下一（控件 5，I→II→III→IV→I，⭐ 2026-10-31） |
| `t_loop` | 文本 | (540, 160, 452, 46) | `● 循环录音中 REC` | 65535 / 52517 | ③ | FPGA 回显文字 + **四态配色**（`.bco=`/`.pco=` 色帧已落地，见 §八-2） |
| 🔥 `b_rec` | **按钮** | (736, 166, 70, 34) | `●录` | 2459 / 65535 | ② | 叠放在 t_loop 右端上层，录/停切换（控件 9，⭐ 2026-10-31） |
| 🔥 `b_play` | **按钮** | (812, 166, 70, 34) | `►播` | 2459 / 65535 | ② | 同上，播/停切换（控件 10，⭐ 2026-10-31；⚠️ 用 ► U+25BA，⛔ 不用 ▶ U+25B6，字库没有） |
| 🔥 `b_clear` | **按钮** | (888, 166, 84, 34) | `清空` | 2459 / 52517 | ② | 同上，清空该层（控件 11，⭐ 2026-10-31） |
| `t_kd` | 文本 | (540, 214, 452, 40) | `键盘打鼓: 关闭 [音符演奏]` | 9509 / 63455 | ② | FPGA 回显 |
| 🔥 `b_kd` | **按钮** | (912, 218, 72, 32) | `打鼓` | 2459 / 65535 | ② | 叠放在 t_kd 右端上层，键盘打鼓开/关（控件 6，⭐ 2026-10-31） |

### 4. 卡片 C：物理外设监视区

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

### 5. 卡片 D：多维调制生态区

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

### 6. 底部常驻状态条（y: 520..596）

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

---

## 四、Page 1：五级效果器拓扑链中枢

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

### 1. 顶栏（y: 0..44）

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

### 2. 五通道单块（x: 24..1000，每块宽 162，y: 62..514）

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

### 3. 底部（y: 532..592）

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

---

## 五、颜色速查（RGB565 十进制，⭐ 上位机里填这个）

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

> ⭐ 颜色列序实证为 **(前景 pco, 背景 bco)**：如按钮填 65535/2907 = 蓝底白字。

---

## 六、⭐⭐ 事件代码速查（逐个粘进对应事件页）

### ⭐⭐ 6.0-前 · 交互模型总则（先读这个，防走弯路）

> ⭐ 2026-10-30 补：很容易误以为"点按钮后要把所有变化写进按钮事件里"——**⛔ 不用**。
> 正确模型三句话：**屏只管发，FPGA 只管算，回显帧管显示**。

| 角色 | 职责 | 体现在哪 |
|---|---|---|
| **屏端事件** | 只写**一行 printh**：把手指动作翻译成一帧发给 FPGA 的报文 | §六各事件 |
| **FPGA** | 收帧 → 改内部状态 → **回发显示帧**：点名 objname 写控件属性（`.txt=` 文字 / `.val=` 数值 / `.bco=`/`.pco=` 颜色） | `uart_ui.v` 回显 FSM（47 字段） |
| **屏固件** | 收到回显帧 → **自动**改对应控件的显示。屏上没有任何"当前状态"变量 | 无需写代码 |

举例（点 b_timbre 切音色的完整闭环）：

```
点按钮 → 屏只发一帧 65 00 03（屏自己什么都不改）
→ FPGA 收到，切 timbre_sel_r，回发 t_timbre.txt="GUITAR"
→ 屏固件按 objname 找到控件、写 .txt 属性 → 大字自动从 BASS 变 GUITAR
```

⛔ **不要在按钮事件里写** `if(timbre==...) t_timbre.txt=...` 这类记账逻辑——状态源在 FPGA，
屏自己记账必然与 FPGA 失步。上位机里填的默认文字只是**上电初始值**，运行时由 FPGA 回显覆盖。

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

### 6.0 屏→FPGA 命令总表（⭐ 与 uart_ui.v rx 解析逐条对应）

| 命令 | HEX 帧 | FPGA 行为 | 状态 |
|---|---|---|---|
| 模式翻转 | `65 00 00` + 尾 | mode 翻转 + 回显 t_mode | ✅ 一直支持 |
| Test Mode 切档 | `65 00 02` + 尾 | 关→4→8→16→32→关 + 回显 t1 | ✅ 一直支持 |
| 🔥 音色循环 | `65 00 03` + 尾 | timbre_sel 0→1→2→3→0 + 回显 t_timbre + 下游（note_manager/looper/led#0）同步 | ✅ **2026-10-30 落地** |
| 🔥 滑音开/关 | `65 00 04` + 尾 | slide_en 翻转 + 回显 t_slide + 下游滑音链 | ✅ **2026-10-31 落地** |
| 🔥 鼓机节奏下一 | `65 00 05` + 尾 | drum_pattern 0→1→2→3→0 + 回显 t_drum | ✅ **2026-10-31 落地** |
| 🔥 键盘打鼓开关 | `65 00 06` + 尾 | key_drum 翻转 + 回显 t_kd | ✅ **2026-10-31 落地** |
| 🔥 移调 +1 半音 | `65 00 07` + 尾 | trans_semi +1（fader_gear 内限 +12）+ 回显 t_trans | ✅ **2026-10-31 落地** |
| 🔥 移调 −1 半音 | `65 00 08` + 尾 | trans_semi −1（限 −12）+ 回显 t_trans | ✅ **2026-10-31 落地** |
| 🔥 循环录音 | `65 00 09` + 尾 | looper 录/停切换 + 回显 t_loop（四态配色） | ✅ **2026-10-31 落地** |
| 🔥 循环播放 | `65 00 0A` + 尾 | looper 播/停切换 + 回显 t_loop | ✅ **2026-10-31 落地** |
| 🔥 循环清空 | `65 00 0B` + 尾 | looper 清空该层 + 回显 t_loop | ✅ **2026-10-31 落地** |
| 🔥 推子档位下一 | `65 00 0C` + 尾 | 档位循环 + 回显 t_gear/cur/gr | ✅ **2026-10-31 落地** |
| 🔥 BPM +5 | `65 00 0D` + 尾 | BPM shadow +5（≤240）→ 小节线对齐生效 + 回显 t_bpm | ✅ **2026-10-31 落地** |
| 🔥 BPM −5 | `65 00 0E` + 尾 | BPM shadow −5（≥40）→ 同上 | ✅ **2026-10-31 落地** |
| 起始音（绝对） | `71 01 <val>` | val>>1 落 base_semi + 回显 t_base | ✅ 一直支持 |
| ⭐ 八度循环 | `71 1B 01` | base_semi 0→12→24→0 + 回显 t_base | ✅ **2026-10-29 落地** |
| 效果器掩码（绝对） | `71 10 <mask>` | fx_mask 直写 | ✅ 一直支持 |
| ⭐ 效果器翻转 | `71 19 <bit>` | fx_mask ^= bit + 回显**六帧**（三状态条 + 三灯） | ✅ **2026-10-29 落地** |
| 效果器参数 ×8 | `71 11..18 <val>` | 增益/补偿/mix/fb/depth/rate/延迟长/合唱长 | ✅ 一直支持 |
| 切档选择 | `71 05 <1/2>` | 推子档位（音高/音量颤音） | ✅ 一直支持 |
| ⭐ 全量重发 | `88` + 尾 | **47 帧全量回显**（page0 22 + page1 25，约 1138 字节，**每次都发**） | ✅ **2026-10-29 落地** |

> ⚠️ 帧尾 `FF FF FF` 为屏指令结束符，`printh` 里必须带上（下同）。⛔ 0x65 帧只认控件 ID **0..14**（其余静默丢弃）。
> ⭐⭐ **FPGA→屏回显帧型（5 种）**：`.txt="`（文本）/ `.val=`（数值）/ `.tim=`（心跳定时器）/ `.bco=`（背景色）/
> `.pco=`（前景色）——两种色帧为 §八-2 三态配色新增，色值 = RGB565 十进制原样 ASCII。

### 心跳闪烁（page0）

**tm0**（定时器，tim=500，en=1）事件：
```
if(p_hb.val==0)
{
  p_hb.val=1
}else
{
  p_hb.val=0
}
```

**tm1**（定时器，tim=1500，en=1）事件：
```
tm0.en=1
```

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

### ⭐ page0 / page1 后初始化事件（切页返回刷新，⭐ 两页都要加）

```
printh 88 FF FF FF
```

> **为什么要加**：切页期间 FPGA 发的本页更新帧会被屏丢弃（页私有）⇒ 返回显示旧值。
> 0x88 **每次收到都全量重发 47 帧**（2026-10-29 RTL）⇒ 每次回到该页自动拿最新全量
> （page1 的仪表 / 文本 / cur / gr 也一并刷新）。

### 基准音切八度（b_oct）

**b_oct** 弹起事件——⭐ **单命令版（本轮 RTL 0x1B 已落地，推荐）**：
```
printh 71 1B 01 FF FF FF
```

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

### 模式切换（b_mode）

**b_mode** 弹起事件（RTL 实锤：触摸 ID 0 = 模式翻转）：
```
printh 65 00 00 FF FF FF
```

### 🔥 音色循环（b_timbre 按钮 / h_timbre 热区，⭐ 2026-10-30 新增）

**b_timbre 按钮或 h_timbre 热区**弹起事件（RTL 实锤：触摸 ID 3 = 音色循环请求，两者发同一帧、RTL 无感知）：
```
printh 65 00 03 FF FF FF
```

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

### Test Mode 切档（b_test）

**b_test** 弹起事件（RTL 实锤：触摸 ID 2）：
```
printh 65 00 02 FF FF FF
```

### 🔥🔥 page0 控制面板按钮组（⭐ 2026-10-31 新增 11 个）

**每个按钮弹起事件一行 printh**（RTL 实锤：控件 4..14，与调试串口同一条下游路径，
回显 FSM 自动刷新对应 t_* 文字，屏**不用记账**）：
```
b_slide：   printh 65 00 04 FF FF FF      // 滑音开/关（↔ 'W'）
b_drum：    printh 65 00 05 FF FF FF      // 节奏型下一（↔ 'D'）
b_kd：      printh 65 00 06 FF FF FF      // 键盘打鼓开/关（↔ 'K'）
b_tr_up：   printh 65 00 07 FF FF FF      // 移调 +1 半音（↔ 'F'）
b_tr_dn：   printh 65 00 08 FF FF FF      // 移调 −1 半音（↔ 'G'）
b_rec：     printh 65 00 09 FF FF FF      // 循环录音（↔ 'R'）
b_play：    printh 65 00 0A FF FF FF      // 循环播放（↔ 'L'）
b_clear：   printh 65 00 0B FF FF FF      // 循环清空（↔ 'C'）
b_gear：    printh 65 00 0C FF FF FF      // 推子档位下一（↔ 'J'）
b_bpm_up：  printh 65 00 0D FF FF FF      // BPM +5（40..240 饱和）
b_bpm_dn：  printh 65 00 0E FF FF FF      // BPM −5
```

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

### 切页按钮

**b_fx** 弹起事件：`page page1`
**b_back** 弹起事件：`page page0`

### page1 五个头部按钮

```
b_pv_hdr：  printh 71 05 01 FF FF FF      // 切档 1（音高颤音）
b_vv_hdr：  printh 71 05 02 FF FF FF      // 切档 2（音量颤音）
b_dist_hdr：printh 71 19 01 FF FF FF      // ⭐ 翻转失真 Bit0
b_chor_hdr：printh 71 19 02 FF FF FF      // ⭐ 翻转合唱 Bit1
b_dly_hdr： printh 71 19 04 FF FF FF      // ⭐ 翻转延迟 Bit2
```

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

---

## 七、⭐⭐ 字库字符集（⭐ 生成 6 份，每份粘同一行）

### 7.1 中文（一次全选复制）

```
演奏核心节奏循环无拍器物理外设监视调制与投生态指板模式变调音高颤量开关启闭基准最低原录音回放武装中空闲键盘打键位演奏主延踏板踩使能松推子控制档实示波波形显示李萨如图谱失真合硬件直通级共干湿比反馈路独立进五效果拓扑链点击切八度旋钮锁定增益补偿延迟时间长度模拟磁立体声返回看板深度速率正在调节锁状态响色滑鼓播
```

> ⭐ **2026-10-31 补末尾 4 字：色 滑 鼓 播** —— 🔴 按钮文字专用（切音色 / 滑音 / 打鼓 / ►播）。
> 🔴 **这是“按钮文字不显示”的头号根因**：按钮的文案和文本控件一样**走字库**，
> 字库生成时字符集里没这个字 ⇒ 屏上就是**空白**（中文）或方块（符号）。
> ⚠️ 按钮还要单独检查属性面板的 **font（字库）选了哪一档**（按钮统一选 ② 16px 那档）。

### 7.2 🔴 特殊符号（⛔ 不加必显示方块）

```
● ➔ ⬅ ★ ► ─ · ↕
```

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

### 7.3 ASCII

字库工具勾选完整 ASCII（数字/字母/括号/百分号/冒号/方括号等全用到了）。

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

---

## 八、⚠️ 已知边界与后续工作

### 1. z_pd / z_vd 两页重名（合法但要懂行为）

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

### 2. t_loop 多态配色 ✅ 已落地（2026-10-29 RTL）

FPGA 加发 `t_loop.bco=` / `t_loop.pco=` 色帧（帧型新增），文案与配色**同源同发**（st_loop 变化 ⇒ 三帧齐挂起）：

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

### 3. Page1 动态数据 ✅ 已落地（2026-10-29 RTL）

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

### 4. led_* 状态灯 ✅ 已落地（2026-10-29 RTL）

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

---

## 九、✅ 验收清单

### 模拟器（不接 FPGA）

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

### 串口助手联调（USB-TTL 接屏，115200）

| # | 发什么（HEX） | 期望 |
|---|---|---|
| 1 | `00 FF FF FF` | 清缓冲（上电防杂波，官方 QA25） |
| 2 | `88 FF FF FF` | 🔴 **收到 47 帧全量回显**（约 1138 字节，page0 22 + page1 25）——最硬一条 |
| 3 | **再发一次** `88 FF FF FF` | ⭐ **又收到 47 帧**（重发已落地；旧 RTL 第二次只回心跳） |
| 4 | `71 19 01 FF FF FF` | ⭐ 失真**六帧**联动（三状态条 + 三灯；`失真 [关]`↔`[开]`、led_dist 0↔1） |
| 5 | `71 1B 01 FF FF FF` ×3 | ⭐ t_base 依次 C4→C5→C6→C4 循环 |
| 6 | 等 1s | 心跳帧 `tm1.tim=1500` 每秒一帧，圆点常闪不灭 |
| 7 | `71 11 <val> FF FF FF` | ⭐ 增益写 ⇒ page1 `z_dg.val=` + `t_dg_val.txt=` 同源两帧（值为满量程百分比） |
| 8 | `71 13 <val> FF FF FF` | ⭐ 混合写 ⇒ `z_mx.val=` + `t_mx_val.txt=`（混合=**0x13**，见 cur 码口径） |
| 9 | 🔥 `65 00 03 FF FF FF` ×4 | ⭐ 音色循环：t_timbre 依次 BASS→GUITAR→PIANO→PAD→BASS（⭐ 2026-10-30 落地） |
| 10 | 🔥 `65 00 04 FF FF FF` | ⭐ 滑音开/关：t_slide `开启↔关闭` 翻转 |
| 11 | 🔥 `65 00 05 FF FF FF` ×4 | ⭐ 节奏型循环：t_drum I→II→III→IV→I |
| 12 | 🔥 `65 00 07 FF FF FF` ×2 | ⭐ 移调：t_trans `0 SEMI`→`+1`→`+2` |
| 13 | 🔥 `65 00 08 FF FF FF` | ⭐ 移调回：t_trans `+2`→`+1` |
| 14 | 🔥 `65 00 09 / 0A / 0B` | ⭐ 循环三键：t_loop 四态文字+配色联动（录音中按 0B 回空闲） |
| 15 | 🔥 `65 00 0D FF FF FF` ×3 | ⭐ BPM：t_bpm 120→125→130→135（⚠️ 小节线对齐，最长等一小节） |
| 16 | 🔥 `65 00 0E FF FF FF` | ⭐ BPM 回落：135→130 |

> ⚠️ 判据 2 若只收到部分帧：检查控件名是否与本清单逐字一致（t_base 不能叫 tBase）。
> ⚠️ 帧尾 `FF FF FF` 是屏的指令结束符，FPGA 自动处理；串口助手手动发时切 HEX 模式补发。
> ⭐ **上板前先跑仿真**：`tb/w3c/tb_uart_ui.sv` 回归 **340 checks PASS**（iverilog），覆盖 47 帧全量 burst、
> fxmask 六帧联动、t_loop 多态配色、page1 25 字段、cur 码 0x11..0x18 口径、b_timbre 音色闭环、
> 控件 4..14 面板脉冲独热+严格单拍、未知控件 15/bit7 别名负判据等。

---

## 十、⭐ 终稿规格速查表对齐核对（2026-10-30）

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

### 15 组字段核对矩阵（page0）

| # | 字段 | 终稿要求 | RTL 现状 | 结论 |
|---|---|---|---|---|
| 1 | t_timbre | BASS/GUITAR/PIANO/PAD 循环 | 四态循环，b_timbre 闭环 + 点后大字由回显帧自动同步 | ✅ 对齐 |
| 2 | t_mode | 指板 ⇄ 钢琴 | `指板模式/钢琴模式` 二态，b_mode 闭环 | ✅ 对齐 |
| 3 | t_base | C4/C5/C6 循环 | b_oct 三档循环（验收判据 5） | ✅ 对齐 |
| 4 | t_trans | -12 ~ +12 半音 | 符号+数值（`+1 SEMI` 等） | ✅ 对齐 |
| 5 | t_slide | 开/关 | `开启/关闭` 翻转 | ✅ 对齐 |
| 6 | t_bpm | 40~240 大字号 | BPM 数值帧 + shadow 对齐 | ✅ 对齐 |
| 7 | t_loop 空闲态 | `空闲` | 一致 | ✅ 对齐 |
| 8 | t_loop 回放态 | `▶ 循环回放中 PLAY` | 🔥 2026-10-30 已修：`●`→`►`（U+25BA；⛔ 不用 ▶ U+25B6，§7.2 字库集里是 ►） | ✅ 已修 |
| 9 | t_kd | 键盘打鼓状态 | 一致 | ✅ 对齐 |
| 10 | t_vol | 主音量监视 | 一致（屏控增益化另议） | ✅ 对齐 |
| 11 | t_pedal | 延音踏板 | 一致 | ✅ 对齐 |
| 12 | t_hdmi | 实时示波器/李萨如/彩虹FFT | 三态一致 | ✅ 对齐 |
| 13 | t_pd / t_vd | 外设监视弧 | 一致（页私有见 §八-1） | ✅ 对齐 |
| 14 | 底部三灯 + b_fx | led_dist/chor/dly + 跳转 | fx_mask 六帧联动（§八-4） | ✅ 对齐 |
| 15 | t_drum / t_gear / t_lock | 见下三项 | — | ⚠️ **3 处待裁定** |

### ⚠️ 3 处结构性差异（待用户裁定）

| 字段 | 终稿写法 | RTL 现状（证据） | 差异与建议 |
|---|---|---|---|
| t_drum | `关 / 开 I / II / III / IV` 五态 | `drum_pattern_r` 为 2 位循环计数器、**无使能位**（`rtl/top.v:1089-1093`），只有 `开 I..IV` 四态 | 要"关"档需新增 `drum_en` 寄存器 + rx 命令 + 屏按钮；**不改则联调时按四态验收** |
| t_gear | `档0变调/档1音高颤音/档2音量颤音`（0 基） | 显示 `st_gear_c+1`（档1变调/档2音高颤音/档3音量颤音，**1 基**） | 二选一：RTL 改 0 基（去掉 +1）或终稿改 1 基；**1 基更符合日常读法，建议改终稿** |
| t_lock | `实时/锁定` | **屏端静态文本**，FPGA 无对应信号（推子锁在屏侧） | 若要 FPGA 驱动需新增锁状态通路；**现状屏自治即可，建议保持** |

---

## 附 · 关联

| 想看什么 | 去哪 |
|---|---|
| ⭐ FPGA 回显实现（48 字段全动态 + 心跳 + 三件套 + 音色按钮闭环 + page0 面板 11 按钮） | `rtl/w3c/uart_ui.v` · tb：`tb/w3c/tb_uart_ui.sv`（340 checks） |
| ⭐ 心跳圆点 PNG 生成脚本 | `tools/gen_hb_dots.py` → `tools/hb_dots/` |
| ⭐ 改档记录（500k→115200） | `rtl/top.v` :1243-1250 |
| 修正过程存档（12 处 v2 错误对照） | `hmi7/串口屏v2-修订版-20261029.md` |
| 旧 2 寸屏（ESP32 侧）文档 | `esp32/串口屏控件清单.md` 等（⛔ 与本屏无关，别混用） |
