hokuu1102/Gowin2026-PolySynth/evidence/main_fix_20261014/combined_no_writepipe/RELEASE_NOTES_ZH.md

# AZ 组合候选交接说明（2026-10-14）

## 版本定位

发布分支：`codex/combined-core-no-writepipe-20261014`。
实际构建及回归源码：`a529bbd2b9daa935508d55b7963c6e4258f66f55`；后续提交仅归档证据和整理说明。
本版是上板候选，软件与时序门槛已通过，**未上板验收**。
不合并或替换 main，不引入队友其他分支的新功能。

## 已组合的修复

| 项目 | 内容 |
| --- | --- |
| 行程比例滑音 | 按两轴校准行程比例跟随；手指停住，音高停住，不再自动滑向 B |
| 切模式释放 | 多轴持音记录保留至对应 OFF，避免切模式后松键无法释放 |
| 指板连续拨弦 | 保留已触发轴的释放记录，避免旧音符遗留 |
| 滑音持音与释放 | A 松开、B 按住时保持原声部；结束时释放一次，取消过期或重复 OFF |
| FIFO 溢出清零 | 清历史状态与新丢弃同拍时保留新丢弃，标志为 1、计数为 1 |
| 通知逻辑优化 | 无新增周期，减少通知状态使能逻辑；公开 UART/SPI/I2S 逐拍等价已核验 |
| 验收加强 | 未知值、无明确结论、负向测试及诊断复现分别处理；补真实双 UART 隔离测试 |

完整保留原有功能。系统和音频仍用 50 MHz 直接时钟体系；没有新增系统 PLL、CPU、HLS。
现有 HDMI 时钟实现未改。硬件 ADC 参数未改，Y 导出仍为 9 字节，FFT 暂不新增。
滑音仍在指板模式通过 W 开关，键盘模式不执行滑音。

FIFO 写入分拍**不在本版中**。备选完整历史位于 `a9227e3`；本机同时保留
`codex/backup-fifo-writepipe-20261014` 分支。该备选多占 287 CLS，故未升为本版。

## 本版独立验收

178 个测试入口，选择 175 项：**173 功能 PASS、1 预期负向通过、1 单列诊断复现、0 失败**。
3 个历史/手动夹具跳过，不计为通过。完整名单与逐项日志位于 `../combined_full/`。
裸解析器接入混合屏字节的伪事件复现不是整机功能通过；真实顶层双 UART 隔离已通过。
真实 UART/SPI/拨弦到 I2S 的滑音场景、键到出声及松键静音、回放尾音、变调均通过仿真。

新鲜综合及布局布线退出码 0；73 构建输入哈希一致，280 仿真源文件核验。

| 指标 | 本版 |
| --- | ---: |
| 原生 sys 时序目标 | 16.4 ns（未放宽） |
| 系统 Fmax | 60.989 MHz |
| Setup / Hold 裕量 | 0.004 / 0.211 ns |
| Recovery / Removal 裕量 | 0.866 / 0.123 ns |
| Setup / Hold 违例 | 0 / 0 |
| CLS / BRAM / DSP | 25,096 / 69 / 24 |

Hold ≥0.05 ns 门槛通过；严格 setup 目标仅余 **4 ps**，不能宣称裕量宽裕。
工具的既有放置和通用时钟路由告警保留在日志中，不视为已经完成实板验证。

## 文件与回退

`completion.json`、`metrics.json`、`build_exit.json`、`product_inputs.csv` 和 `reports/`
提供固件来源、原始时序/资源报告及验收证据。`Pushed: false` 是构建归档时的状态快照，
不是实时远端状态。软件回归源为本版，不借用 AY 或分拍备选结果。

本地烧录文件：`AZ_combined_core_NO_WRITEPIPE_TIMING_PASS_BOARD_UNVERIFIED_20261014.fs`，
存于用户原 `bitstreams` 文件夹，未覆盖旧版；19,913,047 字节，SHA256：
`28C94FE99FF13DBEAED459A1CD2B7F9531B708BA94AF2E768371499F9EC2822B`。
遵循仓库现有忽略规则，`.fs` 不纳入此次 Git 推送；源码、测试和报告入库。
构建路径必须全 ASCII，中文归档目录仅用于存放产物。

回退比较：AY 为 `364f662`；FIFO 溢出修复为 `d4f4c66`；分拍备选完整快照为 `a9227e3`。
建议在独立 checkout 中选择历史提交，不覆盖队友或主工程的未提交修改。
