hokuu1102/Gowin2026-PolySynth/docs/releases/guide-fix-20261101/README.md

# 灌谱指引漏灯修复：本地验收记录

本记录整理已验证的交付版本，仅作本地提交，未推送远端。

## 版本对应

- 基线归档：`612b98da52ef84be640aa7877ac80cd3d863d8fb`（52.400MHz版本）。
- 实际编译源码：`6560f67bfcae0e8c31d9e00635266ca71942c361`。
- 本目录提交只整理验收证据，不修改RTL、约束或编译配置。烧录件对应上述源码提交，而非后续文档提交。
- 器件：`GW5AT-LV60PG484AC1/I0`；实际系统时钟50MHz。

## 修复行为

原有节拍亮窗会遮住暗区内的短指引音符，出现声音正确但对应LED未亮。现在每个获准且可映射的指引ON独立触发对应键50ms提示，同音重复重新计时。OFF仍按原有身份配对关闭账本，显示尾脉冲可持续至到期；长音保留节拍闪烁，实体按键优先常亮。新谱、重新起播和复位清尾脉冲，停谱沿用原有流超时。

保留64个音符身份槽、32位重复计数及原账本内部逐拍行为。指引入口将音符、变调与模式一起采样，显示增加一拍20ns；声音与Loop不增加延迟。颤音速率步进的组合逻辑改写通过原版模型逐拍对照。灌谱协议、串口速率和IO约束不变。

同键两次ON间隔小于50ms时可能连续亮，不强制插入暗间隔；不可映射到现有实体键的音符沿用原有处理。

## 验证与边界

- 22项针对性检查全部通过，未重跑完整回归。
- 覆盖360个缩放拍内位置、真实50MHz下50ms脉宽、计时回绕、重复音、重叠音、容量、变调/模式、OFF配对、新谱与重播、实体按键消隐和实际LED串行锁存/OE。
- 原始漏灯复现修复后通过；顶层快照对照通过，故意取消控制快照的错误版本被检出。
- 颤音原版模型对照覆盖5组参数、20480次状态转移。
- 原有时序验收脚本退出码0；Fmax **50.905MHz**，实际20ns周期Setup余量 **+0.356ns**。
- Hold / Recovery / Removal最低余量分别为 **+0.178 / +0.284 / +0.203ns**。
- 更严的16.4ns布局优化预算Setup仍为 **-3.244ns**，不宣称该收紧预算全部通过。
- 实机验收待完成，需用原漏灯曲目上板复测。旧归档烧录件保留。

## 本地交付文件

交付目录：`D:/ChatGPT/Outputs/FPGA-guide-fix-20261101/delivery/`。

- 烧录件：`Gowin2026-51-HMI-guide-fix-50MHz-pass-20261101.fs`
- 烧录件SHA256：`9812b0ba0dfac4098310f7465e35ee67fcde1b8ef876ea6e93dc20ff22812270`
- 源码包：`FPGA-51-HMI-guide-fix-source-20261101.zip`
- 源码包SHA256：`65da9705368ae476d450a7477258b3c45f4a36e0c6137ed3b5f63ef4d99a7a6c`

交付目录保留原生STA、资源报告、路径报告、逐项测试日志和全部文件校验和。本目录纳入版本控制的manifest、编译输入哈希、测试清单和验收门日志用于绑定源码与交付物；烧录二进制和中间编译产物仍保存在输出目录。
