hokuu1102/Gowin2026-PolySynth/fix_evidence/修复结果-20261020.md

# 功能修复结果 · 2026-10-20

功能代码修复已完成，仿真及离线验证通过。按用户“时序退化不要紧，先把功能修完”的最新要求，**时序收敛暂缓**。当前构建不是时序验收版本，没有发布或烧录。

修复基线为远端 `cd63b0773480e43b19d47f7b541d202a0a66df4d`；`c6b9aad` 保存原始审查证据。原审查结论保留在 `review/`，修复后的验证记录位于本目录和 `sim/evidence/`。

## 原审查确认项

| 项目 | 修复及验证 |
|---|---|
| R1 音量渐变无符号回绕 | 按剩余距离饱和逼近。验证 37→0、零增益持续 1,025 个音频 tick、接近 65,535 的上调和下调均不越界。`tb_master_mix_boundaries` 通过。 |
| R2 FXSTAT 命令被当作未知字节 | 把已定义的命令识别项纳入分派；ASCII 与二进制命令链测试通过，未知命令计数保持 0。`tb_calib_cmd_fxstat` 通过。 |
| R3 切模式/移调后 OFF 灭错灯 | 保存 ON 的原始身份及当时映射的灯键，OFF 消费已有记录。模式切换及移调后的最后一次 OFF 均清零。 |
| R4 第八个重叠引用提前灭灯 | 不再使用饱和到 7 的计数。不同身份独立保留，重复身份使用 32 位计数。16 个独立身份以及同一身份 65,536 次 ON、65,535 次 OFF 的剩余亮灯测试通过；超时后状态完整清除。 |
| R5 把系统时钟余量错误借给其他时钟 | 对各时钟分别判定，并读取原生 setup、hold、recovery、removal 表。只有明确属于 clk_sys R→R 且 relation=16.4 ns 的路径可获得到实际 20 ns 周期的差值；10 ns 特例不获放宽。9 个正反报告夹具通过。 |
| R6 暂存坏证据被工作区 PASS 掩盖 | 按 Git 暂存区对象检查，支持 UTF-16 诊断和含空格路径；批量读取对象。12 个正反场景通过，包括暂存 FAIL、空日志、LEAK、工作区缺失和多个对象。正常空 compile/stderr 通道允许为空，非空诊断继续检查污染。真实仓库的 1,018 个既有证据条目检查通过。 |
| R7 合法父目录引用误报 | 合并基准路径后进行规范化，保留点目录，拒绝越出仓库的候选路径。合法 父级两层的 rtl 目录（路径规范化示例）、缺失文件和越界反例均通过。 |
| R8 HDMI reset recovery 为负 | 改用字时钟同步复位，并增加靠近 TMDS I/O 的低扇出复位寄存器。最新原生 recovery 最差 **+0.250 ns**，removal **+0.203 ns**，原来失败的双沿检查保留。复位初始有效、在同步字边界释放的功能仿真通过。整体 setup 尚未收敛，见下文。 |
| S1 上行轴丢失导致和弦显示缺音 | 旋律保留真实轴，鼓继续由 bit6 显式区分。真实 top 组帧输出的轴 5/6 均保留；网页也兼容旧固件同轴和弦，音符与鼓独立配对。top 组帧、串口音色和实际网页绘制探针通过。 |
| S2 STOP/RESET 与发送游标竞态 | UART 发送及游标提交在同一互斥区完成，循环重检运行状态，自然结束也在锁内复核。原代码交错测试失败，修复代码通过；停止/重置返回后没有旧 note_on，RESET 游标保持 0，STOP 不误标为自然结束。 |
| S3 BLE 通知失败后丢字节 | 先 peek，通知成功才 discard 并累计 out；失败保留剩余数据重试。20 字节成功、下一段失败、重试 8 字节后共 28 字节逐字节一致，环形回绕测试通过。 |
| S4 MIDI 力度 128 导出为零 | 正确缩放 8 位力度到 7 位，正力度最小为 1。0/1/128/255 边界测试通过。 |
| S5 原始录音 .bin 变空 | 原始字节独立快照保存，不再复用会被消费的解析缓冲。两页均验证跨帧碎片、调用方修改临时数组后仍能完整导出 28 字节；重置会清除旧录音。 |

## 同时完成的配套修复

- 超时不再读取上一轮日志并误报“已有 PASS”，只记录本轮没有在期限内返回结论。重复正反场景已验证。回归脚本新增准确筛选、关闭波形文件、调整时间预算的选项，断言和退出码要求保持不变。
- 修正过期的网页/协议自检、鼓字段判据和离线测试注册。44 个工具全部通过，最近一次完整离线汇总为 **1,062 项 OK、0 项 RED**。
- 历史 Python `evt2midi` 按音频采样率解释完整 32 位 phase_inc；保留音色/鼓型，按音高配对旧固件同轴和弦，为截断录制补发 OFF。输出带轨名的 Format 1 MIDI；真实 Python 导出再交给真实网页灌谱转换，四种音色和四件鼓均保留。
- 纠正构建检查把 Gowin V1.9.12.03 干净运行自动生成的 `Map_Option=1` 当作非法配置的问题。保留 Map=0 的兼容性，Place/Route 仍要求 0，未知配置仍拒绝。6 个配置正反夹具和静态检查 7/7 通过。
- 删除工程文件中两条重复源文件记录，唯一编译输入集合保持一致；更新与实际实现冲突的注释。注释修改的逻辑等价检查保存在 `editorial-equivalence.json`。

## 测试范围

- 原有默认全量回归：**218 项执行，0 项失败**；含原有诊断和预期负向用例，不能把每项都解释成独立功能证明。原有 3 个默认跳过的工具/诊断 bench 保持原策略。
- 新增 5 个定向 bench：音量边界、FXSTAT、指引身份/引用、top 上行身份、HDMI 复位，均通过。
- 引用计数后续修改后，相关 4 项 guide 回归及停播清灯用例已重跑通过。
- 网页实际脚本、Python 实际解析/导出和 ESP32 实际生产 C 代码的主机探针均通过。C 探针对 SDK/RTOS 边界使用桩；**未进行 ESP-IDF 目标整包编译，也没有上板/BLE 实机验收**。
- 二次代码审查及两个发现的后续修复见 `review-followup.md`。

指引状态支持 16 个不同的未结束映射身份；重复引用单独计数。没有声称任意数量不同身份的乐谱均可无损表示。跨映射的同轴同音重复事件按确定的首个匹配记录消费，协议没有独立 ON 实例编号。

## 已明确暂缓的时序问题

最新原生构建返回 **12**，原始报告位于 `physical-latest/report.html`，结构化数据位于 `sta-candidate3.json`。

| 原生检查 | 最差 slack |
|---|---:|
| Setup（16.4 ns 预算） | −10.180 ns |
| Setup 对实际 20 ns 周期 | −6.580 ns |
| Hold | +0.148 ns |
| Recovery | +0.250 ns |
| Removal | +0.203 ns |

Setup 有 2,094 个违例端点，TNS −5,336.735 ns。最差路径从 `g_sound.u_fader_gear/enc_r_3_s1/Q` 到 `u_guide_lamp/held_count_held_count_RAMREG_1_G[158]_s0/RESET`，数据延迟 26.253 ns。功能扩展后的指引计数/选择路径是下一步流水化或局部重构的定位起点。按最新要求，本次不继续为其时序收敛更改结构，也没有放宽时序门来制造通过。

HDMI 原先的 recovery 失败已转正，但这不等于整机时序或上板功能已经通过。OSER RESET 是异步输入，相关检查应保留：[Gowin FPGA Primitive 官方说明](https://www.gowinsemi.com/upload/database_doc/39/document/5bfcff2ce0b72.pdf)。
