hokuu1102/Gowin2026-PolySynth/files/00-总览/进度日志-20261001.md

# 📋 进度日志 · 2026-10-01 凌晨（⭐ 主树整合后的连续工作）

> **工作根目录**：⭐ `C:\Users\hokuu\Desktop\FPGA\FPGA2026`（⭐ 用户裁定"以后都回主树写" ✅）
> **依据**：⭐ 用户对该日《待你拍板清单》34 条的答复 ✅
> **配套**：⭐ `今晚任务书-20260930夜.md`（⭐ 铁律 ＋ BATCH 清单）· ⭐ `你的答复-20261001.md`（⭐ 34 条全文）

---

## 一、⭐ 已完成的"大部分"（⭐ 每个都走了完整门序）

### ⭐⭐ 大部分 A · 仓库整合 ＋ 队友 HDMI 合并

| ⭐ 项 | ⭐ 结果 |
|---|---|
| ⭐ **worktree 整合** | ⭐ **30 → 22** ✅（⭐ 删 7 个已并入的 ＋ ⭐ 1 个干净的 ✅）|
| ⭐ **删前三重存档** | ⭐ `.patch`（⭐ 7 份）＋ ⭐ `wip` 提交（⭐ 各自分支）＋ ⭐ `tag`（⭐ 4 个 detached 的 ✅）⇒ ⭐ **零丢失** ✅ |
| ⭐ **主树快进** | ⭐ `main` 快进到 `deliver`（⭐ `--ff-only` · ⭐ 226 files · ⭐ **零冲突** ✅）|
| ⭐ **合并队友 HDMI** | ⭐ 6 个提交 ⇒ ⭐ ⭐ **640×480 彩条已上板出图** ✅<br>⭐ 真根因：⭐ **TMDS 控制码表 `2'b01`/`2'b10` 写反** ✅ |
| ⭐ **恢复 `synth_only.tcl`** | ⭐ 从 `fix/calib-autotare` 分支恢复 ✅（⭐ 验证了"删前先提交"的价值 ✅）|

### ⭐⭐ 大部分 B · 阈值与量纲（⭐ A2 ＋ BATCH 2）

| ⭐ 项 | ⭐ 改动 | ⭐ commit |
|---|---|---|
| ⭐ **A6/D9 降门槛** | ⭐ `-MinFmax 52.5 → 51.5`（⭐ 5% → **3%**）✅ | `cf2b9fe` |
| ⭐ **A2 `STILL_TOL`** | ⭐ `8 → 48`（⭐ 与 `calib_span` 对齐 ✅） | `c67dc9c` |
| ⭐ **BATCH 2 触发阈值** | ⭐ `EVT_TRIG_TH 64 → 205`（⭐ **5.0%**，⭐ 比章程的 8.6% **更灵敏** ✅）<br>⭐ `EVT_REL_TH 32 → 102`（⭐ 2.5%，⭐ 保持 2:1 迟滞 ✅） | `c67dc9c` |
| ⭐ **文档口径统一** | ⭐ **53 处**（⭐ 26 处改数 ＋ ⭐ 27 处保留历史＋加更正 ✅） | `9ad9491` |

⭐ **四道门全绿**：
```
① 综合门  ：⭐ 0 ERROR · 50 modules · calib_autotare(STILL_TOL=48) ✅
② 聚焦 tb ：⭐ 全绿 ✅
③ PnR     ：⭐ 0 setup / 0 hold · ⭐ Fmax 55.674（+11.348%）· ⭐ PASS ✅
④ 全量回归：⭐ 106 / 106 ✅
```
⭐ **位流归档**：⭐ `build/bitstreams/AN_main_n13_thr_E715A46.*` ✅（⭐ **合规交付候选** ✅）

### ⭐ 大部分 C · BATCH 3（修B：池判据按来源选）

| ⭐ 项 | ⭐ 内容 |
|---|---|
| ⭐ **缺陷** | 🔴 **物理键 14/15（G#3/A#3）无声** ✅ |
| ⭐ **根因** | ⭐ 池与鼓标志**都按轴号判**（⭐ `cur_axis >= 14` / `axis_r[g] >= 14`）⇒ ⭐ 物理键 14/15 被送进 5 个 voice 的保留池 ＋ ⭐ 被打上鼓标志 ✅ |
| ⭐ **修法** | ⭐ 新增 `localparam [2:0] SRC_AUX = 3'd3`；⭐ `pool_mask` 与 `voice_drum_o` **都改按来源** ✅<br>⚠️ **为什么不是 `src != 0`**：⭐ 那样 looper（⭐ `src=4`）也会被判成鼓 ⇒ 🔴 **回放全走噪声表** ✅ |
| ⭐ **依据** | ⭐ 从**原始实现**（⭐ `feat/pool-src` · ⭐ `9ae0335`）的注释里读出：⭐ "进不进保留池由【源】决定（`cur_src == SRC_AUX`）" ✅ |
| ⭐ **连带改 tb** | ⭐ `tb_note_manager` 的 DUT C 原来 `note_src_i` 硬接 `3'd0` ＋ ⭐ 用轴 14/15 命中保留池 ⇒ ⭐ 改为**可变 `c_src`** ＋ ⭐ **新增正面判据**："手弹（`src=0`）的轴 14 落在**普通池**" ✅（⭐ 那就是"键 14/15 出声"的判据 ✅）|
| ⭐ **聚焦 tb** | ⭐ `drum` 3/3 · ⭐ `metronome` 1/1 · ⭐ `note_manager` 1/1 · ⭐ `looper_tail` 1/1 · ⭐ `perc_env` 2/2 · ⭐ `wavetable_bank` 2/2 ⇒ ⭐ **全过** ✅ |
| ⭐ **综合门** | ⭐ **0 ERROR** · ⭐ 50 modules ✅ |
| ⏳ **PnR ＋ 全量回归** | ⭐ 进行中 |
| ⚠️ **还欠** | ⚠️ 章程 `§26.3` 要求 **a~f 六条判据** ⇒ ⭐ 新 tb `tb_pool_by_src.sv` 覆盖 **a/b/c/d**（⭐ 子代理在写 ✅）|

---

## 二、⭐⭐ 本轮踩到的两个坑（⭐ 都已修，⭐ 都已记录）

| ⭐ | ⭐ 坑 | ⭐ 教训 |
|---|---|---|
| **1** | 🔴 **`edit` 工具写回时会【去掉 BOM】** ⚠️<br>⭐ `tb_all.ps1` 含 10649 个非 ASCII 字节 ⇒ ⭐ 无 BOM ⇒ ⭐ **PS 5.1 按 GBK 解码 ⇒ 整文件解析失败** ❌ | ⭐ **改完任何"含非 ASCII 的 `.ps1`"，⭐ 必须回查首三字节是不是 `EF BB BF`** ✅<br>⭐ 修法：⭐ `[IO.File]::WriteAllText($p, $t, [Text.UTF8Encoding]::new($true))` ✅ |
| **2** | ⚠️ **`tb_vel_top_stream` 的镜像没跟上** ⚠️<br>⭐ 它 `localparam VEL_TRIG_TH = 64`，⭐ 而真 `top.v` 已改 205 ⇒ ⭐ **T6a 假红** ✅ | ⭐ **这些 tb 故意复刻 `top.v` 的常量/公式当判据** ⇒ ⭐ **改源必改镜像** ✅<br>⭐ 且 ⭐ **改镜像后必须保住判据的牙齿**（⭐ 仍测"不过门不发/刚过门发"的**边界** ✅）|

---

## 三、⭐⭐ 两条重要的实测发现

| ⭐ | ⭐ 发现 | ⭐ 影响 |
|---|---|---|
| **1** | ⭐⭐ **PnR 的 Fmax 【同源重跑会波动 ±3.3 MHz】** ⚠️<br>（⭐ 同一份 RTL、⭐ 只差 3 个比较常量：⭐ **52.372 → 55.674** ⚠️；⭐ 布线 23.3 → 11.5 分钟 ✅） | ⚠️ **我昨晚基于两次相同结果（n=2）宣布的"本机 PnR 是确定性的"⇒ 样本不足** ✅<br>⭐ **正确做法**：⭐ **判门槛要用【已观测的最差值】**（⭐ 现为 **+4.744%** ⇒ ⭐ **3% 门槛成立** ✅）<br>⭐ 已落盘：⭐ `Fmax同源波动实测-20261001.md` ✅ |
| **2** | ⭐⭐ **`tb_demo_stall_diag` 记录了一个真上板症状** ⚠️<br>（⭐ 自检和弦响完后，⭐ **前几下按键全不响**；⭐ 要按十几下才出声、⭐ 音高滞后；⭐ 另有挂音） | ⭐ **而仿真里【没有复现】** ✅（⭐ 每次按键都在自己轴上 gate 到 voice ✅ · ⭐ 零丢事件 ✅）<br>⚠️ **但它缩了时序**（⭐ `DEMO_NOTE_DELAY` 10000 vs 板上 2,000,000 ⚠️）⇒ ⭐ **⛔ 不能据此宣布"板上症状不存在"** ✅ |

---

## 四、⏭️ 下一步（⭐ 按序）

```
① ⭐ 等 PnR（pwsh-1181）⇒ 判据 0/0 ＋ Fmax ≥ 51.5
② ⭐ 等 tb 子代理写完 tb_pool_by_src.sv（⭐ 覆盖 §26.3 的 a/b/c/d）
③ ⭐ 跑新 tb ⇒ ⭐ 再做"能红"验证（⭐ 把 RTL 改回按轴 ⇒ ⭐ b/d 必须红）
④ ⭐ 全量回归 ⇒ 判据 106/106（⭐ 或 107/107，⭐ 看新 tb 数）
⑤ ⭐ 归档 BATCH 3 位流 ⇒ ⭐ BATCH 3 收口
⑥ ⭐ 开 BATCH 4（⭐ 方案已备：⭐ `POS_FULL 744→4095` ＋ ⭐ 斜率 `263→48`）
```

---

# ⭐⭐ 追加：2026-10-01 凌晨的后续（⭐ 五个大部分全部收口）

## 五、⭐ 完成清单（⭐ **每个都走了完整四门序**）

| ⭐ | ⭐ 内容 | ⭐ 回归 | ⭐ PnR `Fmax` | ⭐ 位流 | ⭐ commit |
|---|---|---|---|---|---|
| **B** | ⭐ 阈值与量纲（⭐ A2 ＋ BATCH 2 ＋ 门槛 3% ＋ 文档 53 处） | ⭐ **106/106** | ⭐ 55.674（+11.35%） | ⭐ `AN_main_n13_thr` | ⭐ `c67dc9c`…`af4657e` |
| **C** | ⭐ **BATCH 3 修B**（⭐ 池按来源 ＋ ⭐ Z-safe 源解码） | ⭐ **107/107** | ⭐ 52.004（+4.01%） | ⭐ `AO_main_n13_thr_poolsrc` | ⭐ `928c7ed` `35d1ed1` `9e3f393` |
| **D** | ⭐ **BATCH 4 力度量纲** ＋ 🔴 **修 `.sdc` 过紧约束** | ⭐ **107/107** | ⭐⭐ **58.082（+16.16%）** | ⭐ `AP_main_vel4095_sdcfix` | ⭐ `32c7835` `3c9ed7c` `d8bd460` |
| **E** | ⭐ **BATCH 8.1 `'P'` 按轴选片** | ⭐ **108/108** | ⭐ 58.559（+17.12%） | ⭐ `AQ_main_p_probe_axis` | ⭐ `6c019de` `154b6bc` |
| **F** | ⭐ **`adc_farm` 片 1 保持**（⭐ 补 E 的"不充分"那一半） | ⭐ **108/108** | ⭐ 56.114（+12.23%） | ⭐ `AR_main_adcfarm_hold` | ⭐ `8cb8d6f` `d852e8f` |

## 六、⭐⭐ 三个重要发现（⭐ 都改变了判断）

### ⭐ ① `.sdc` 的**量纲错误** —— ⭐ 它一直在压制 `Fmax`

⭐ `set_output_delay -clock clk_sys -max 10.0`（⭐ 加在 `HP_BCK`/`HP_WS`/`HP_DIN` 上）
⭐ 注释的推理是"BCK 半周期 160 ns ⇒ 给 10 ns ⇒ 远小于 160 ns ⇒ 不会误报" ⚠️
🔴 **但 `-max D` 的真实含义是"外部器件要在 `clk_sys` 沿前 D ns 拿到数据"**
⇒ ⭐ **留给 FPGA 的 = 20 − D = 10 ns** ⚠️ ⇒ ⭐ **D 越大越紧**，⭐ 与注释直觉**正好相反** ✅
⇒ ⭐ 而且 BCK 的 320 ns 周期与"相对 `clk_sys` 的约束"**不是同一参考系** ✅
✅ 修法：⭐ `-max 10.0 → 2.0`（⭐ 内部预算 18 ns ⇒ ⭐ **检查没丢**，⛔ 不是 `false_path`）
⭐⭐ **效果：⭐ `Fmax` 从 ~52 涨到 58+** ⇒ ⭐ **之前"±3 MHz 波动"很大一部分是这条约束在放大噪声** ✅

### ⭐ ② `adc_farm` 的**片间不对称** —— ⭐ 它让 `'P'` 在板上**读不到片 1**

⭐ 片 0 走**寄存器**（保持 ✅）· ⭐ 片 1..N-1 走影子 `miso_shift`，⭐ 而它**每次 `cs_fall` 清零** ⚠️
⇒ 🔴 片 1 的数据只在 ~1 µs 内有效（⭐ 占空比 ≈ 0.2% ⚠️）⇒ ⭐ `'P'` 在任意时刻读**必得 0** ✅
✅ 修法：⭐ 加 `shadow_hold`（⭐ 与 `miso_shift` 同拍同式移位，⭐ **只是不清零**）
📌 **为什么不动实时通路**：⭐ 在 `sample_valid` 那一拍两份影子**内容相同**（⭐ 反串行器早于 `done` 数拍收满 ✅）
📌 代价：⭐ `(N_ADC-1)×24` 个触发器 ⇒ ⭐ `N_ADC=2` 时 **24 个** ✅

### ⭐ ③ 两个**工具坑**

| ⭐ | ⭐ 坑 | ⭐ 教训 |
|---|---|---|
| **1** | 🔴 **`edit` 工具写回时会【去掉 BOM】** ⚠️<br>⭐ `tb_all.ps1` 含 10649 个非 ASCII 字节 ⇒ ⭐ 无 BOM ⇒ ⭐ **PS 5.1 按 GBK 解码 ⇒ 整文件解析失败** ❌ | ⭐ **改完任何"含非 ASCII 的 `.ps1`"，⭐ 必须回查首三字节是不是 `EF BB BF`** ✅ |
| **2** | ⚠️ **`tb_vel_top_stream` 的镜像没跟上** ⚠️（⭐ `VEL_TRIG_TH=64` vs ⭐ 真 `top.v` 的 205） | ⭐ **这些 tb 故意复刻 `top.v` 的常量当判据** ⇒ ⭐ **改源必改镜像**，⭐ 且 ⭐ **改完要保住判据的牙齿** ✅ |

## 七、⏭️ 仍未做（⭐ 目标保持 active ✅）

| ⭐ 优先级 | ⭐ 项 | ⭐ 说明 |
|---|---|---|
| 🟠 **P1** | ⭐ **BATCH 8.2 量纲自检** | ⭐ 把 `calib.FULL` 与 `top.POS_FULL` 提成**共享常量** ＋ ⭐ 加**综合期自检**（⭐ 治本，⭐ 防第三次同类错 ✅） |
| 🟠 **P1** | ⭐ **BATCH 8.3 `af_fault`/`mx_fault` 接出** | ⭐ 现在**产生了没人消费** ⇒ ⭐ 故障看不见（⭐ `K-106` 家族 ✅） |
| 🟠 **P1** | ⭐ **BATCH 5 判据缺口**（⭐ `'B'`/`'I'`/音高） | ⭐ 端到端"键 ⇒ `axis_map` 音高"的判据 ✅ |
| 🟡 **P2** | ⭐ **BATCH 6.2 注释↔代码** | ⭐ 3+ 处不一致 ＋ ⭐ `tb_e2e_key_to_sound.sv:36` 的过时注释 ✅ |
| 🟡 **P2** | ⭐ **全量变异测试**（⭐ A3 收工项） | ⭐ 先给 `iverilog` 加并行加速（⭐ 最大收益：⭐ `tb_all.ps1` 是串行的 ✅） |
| 🟢 **P3** | ⭐ **T3 的 19 个未并入分支核查** | ⭐ 出"真未并入"短名单 ✅ |

⚠️ **⛔ `main` 领先 `origin/main` 61 个提交** —— ⭐ **按纪律未 push**，⭐ 等用户同意后**压成 1 个 commit** ✅

---

# APPENDIX -- rounds 98 to 105 (final state of this session)

## Nine large units, each with a full four-gate sequence and an archived bitstream

| unit | content | regression | Fmax | bitstream |
|---|---|---|---|---|
| A | repository consolidation (30 worktrees -> 22) + teammate HDMI merge (colour bar on board) | - | - | - |
| B | thresholds and scale (STILL_TOL 8->48, TRIG 64->205, REL 32->102, gate 5%->3%, 53 doc places) | 106/106 | 55.674 | AN_main_n13_thr |
| C | BATCH 3 by-source pool + Z-safe source decode (keys 14/15 sound) | 107/107 | 52.004 | AO_main_n13_thr_poolsrc |
| D | BATCH 4 velocity scale + the over-tight SDC fix | 107/107 | 58.082 | AP_main_vel4095_sdcfix |
| E | BATCH 8.1 P probe by axis | 108/108 | 58.559 | AQ_main_p_probe_axis |
| F | adc_farm chip-1 hold | 108/108 | 56.114 | AR_main_adcfarm_hold |
| G | BATCH 8.2 scale self-check | 108/108 | 56.114 | AS_main_scale_check |
| H | BATCH 8.3 fault indication on the heartbeat LED | 108/108 | 53.233 | AT_main_fault_led |
| I | fault_any_w declaration scope fix (clears implicit-definition warning) | 108/108 | 62.888 (+25.78%) | AU_main_declfix |

## The six findings that changed my judgement

1. top.sdc set_output_delay -max 10.0 was dimensionally wrong. -max D means the EXTERNAL
   device needs D ns before the clk_sys edge, so a LARGER D is TIGHTER -- the opposite of
   the comment. BCK 320 ns period has no bearing on a clk_sys-relative constraint.
   Fixing it raised Fmax from about 52 to 58 MHz, so much of the 3 MHz "placement noise"
   was this constraint amplifying placement differences.
2. adc_farm is asymmetric: chip 0 reads a holding register, chips 1..N-1 read a shadow
   cleared every cs_fall (~0.2% duty). So the P probe read zero. Fixed with a second
   shadow that shifts identically but never clears.
3. The synthesis gate caught a generate-block scope error (EX3872) that the testbenches
   did not -- the concrete case for the rule that RTL changes go through it.
4. The implicit-definition warning: Gowin tolerates it, so the synthesis gate alone
   cannot prove it fixed. iverilog is the tool that reports it. Check both.
5. Two tooling traps: the edit tool strips the BOM (breaking any non-ASCII .ps1 because
   PowerShell 5.1 then decodes it as GBK), and testbench mirrors of top.v constants must
   be synced while keeping the judgement teeth.
6. T3 has no cheap automatic criterion. git cherry over-reports (a reimplemented feature
   shows as absent) and diff-size is meaningless because main is 73 commits ahead so the
   diff shows main's new code as deletions. It is a manual review task.

## Still open

BATCH 5 judgement gaps (B / I / pitch); BATCH 6.2 comment-vs-code; iverilog parallel
speedup for tb_all.ps1 (serial, ~18 min); the full mutation suite (A3, ~5 h); the T3
manual review of 24 candidates; and true single-sourcing of calib.FULL with CALIB_FULL
(needs the constant hoisted above the u_calib0 instantiation).

main is 73 commits ahead of origin/main and deliberately unpushed.
