hokuu1102/Gowin2026-PolySynth/evidence/q_adc_fix_20261012/after_timing.html

# Timing Messages

Report Title | Timing Analysis Report
Design File | C:\Users\cyx\Documents\ChatGPT\FPGA\Gowin2026-PolySynth-t31b-main\impl\gwsynthesis\Gowin2026.vg
Physical Constraints File | C:\Users\cyx\Documents\ChatGPT\FPGA\Gowin2026-PolySynth-t31b-main\constr\top.cst
Timing Constraint File | C:\Users\cyx\Documents\ChatGPT\FPGA\Gowin2026-PolySynth-t31b-main\constr\top.sdc
Tool Version | V1.9.12.03 (64-bit)
Part Number | GW5AT-LV60PG484AC1/I0
Device | GW5AT-60
Device Version | B
Created Time | Mon Oct 12 21:25:24 2026
Legal Announcement | Copyright (C)2014-2026 Gowin Semiconductor Corporation. All rights reserved.

# Timing Summaries

## STA Tool Run Summary:

Setup Delay Model | Slow 0.93V 0C C1/I0
Hold Delay Model | Fast 0.975V 85C C1/I0
Numbers of Paths Analyzed | 52109
Numbers of Endpoints Analyzed | 55573
Numbers of Falling Endpoints | 28
Numbers of Setup Violated Endpoints | 0
Numbers of Hold Violated Endpoints | 0

## Clock Summary:

NO. | Clock Name | Type | Period | Frequency(MHz) | Rise | Fall | Source | Master | Objects
1 | clk_sys | Base | 20.000 | 50.000 | 0.000 | 10.000 | | | clk
2 | serial_clk | Generated | 8.000 | 125.000 | 0.000 | 4.000 | clk | clk_sys | u_hdmi/u_clk/u_pll/CLKOUT0
3 | pixel_clk | Generated | 40.000 | 25.000 | 0.000 | 20.000 | clk | clk_sys | u_hdmi/u_clk/u_pll/CLKOUT1

## Max Frequency Summary:

NO. | Clock Name | Constraint | Actual Fmax | Logic Level | Entity
1 | clk_sys | 50.000(MHz) | 57.163(MHz) | 16 | TOP
2 | serial_clk | 125.000(MHz) | 1312.981(MHz) | 1 | TOP
3 | pixel_clk | 25.000(MHz) | 33.325(MHz) | 13 | TOP

## Total Negative Slack Summary:

Clock Name | Analysis Type | Endpoints TNS | Number of Endpoints
clk_sys | Setup | 0.000 | 0
clk_sys | Hold | 0.000 | 0
serial_clk | Setup | 0.000 | 0
serial_clk | Hold | 0.000 | 0
pixel_clk | Setup | 0.000 | 0
pixel_clk | Hold | 0.000 | 0

# Timing Details

## Path Slacks Table:

### Setup Paths Table

#### Report Command:report_timing -setup -max_paths 25 -max_common_paths 1

Path Number | Path Slack | From Node | To Node | From Clock | To Clock | Relation | Clock Skew | Data Delay
1 | 0.306 | g_sound.u_fader_gear/gear_o_0_s0/Q | g_sound.u_vibrato_lfo/rate_inc_q_25_s0/D | clk_sys:[R] | clk_sys:[R] | 17.800 | 0.008 | 17.428
2 | 0.315 | g_sound.u_fader_gear/gear_o_0_s0/Q | g_sound.u_vibrato_lfo/rate_inc_q_10_s0/D | clk_sys:[R] | clk_sys:[R] | 17.800 | 0.000 | 17.428
3 | 0.394 | g_sound.u_fader_gear/gear_o_0_s0/Q | g_sound.u_vibrato_lfo/rate_inc_q_13_s0/D | clk_sys:[R] | clk_sys:[R] | 17.800 | 0.008 | 17.346
4 | 0.556 | g_sound.u_calib_span/cur_axis_o_3_s1/Q | g_sound.u_calib1/n909_s/A[0] | clk_sys:[R] | clk_sys:[R] | 17.800 | 0.000 | 13.785
5 | 0.574 | g_sound.u_adc_farm/u_scan0/sample_channel_0_s0/Q | g_sound.u_calib0/n909_s/A[0] | clk_sys:[R] | clk_sys:[R] | 17.800 | 0.008 | 13.758
6 | 0.612 | g_sound.u_calib_span/cur_axis_o_3_s1/Q | g_sound.u_calib1/n909_s/A[3] | clk_sys:[R] | clk_sys:[R] | 17.800 | 0.000 | 13.934
7 | 0.613 | g_sound.u_calib_span/cur_axis_o_3_s1/Q | g_sound.u_calib1/n909_s/A[6] | clk_sys:[R] | clk_sys:[R] | 17.800 | 0.000 | 13.933
8 | 0.645 | g_sound.u_calib_span/cur_axis_o_3_s1/Q | g_sound.u_calib1/n909_s/A[2] | clk_sys:[R] | clk_sys:[R] | 17.800 | 0.000 | 13.754
9 | 0.657 | g_sound.u_adc_farm/u_scan0/sample_channel_0_s0/Q | g_sound.u_calib0/n909_s/A[5] | clk_sys:[R] | clk_sys:[R] | 17.800 | 0.008 | 13.885
10 | 0.657 | g_sound.u_fader_gear/gear_o_0_s0/Q | g_sound.u_vibrato_lfo/rate_inc_q_26_s0/D | clk_sys:[R] | clk_sys:[R] | 17.800 | 0.008 | 17.077
11 | 0.666 | g_sound.u_calib_span/cur_axis_o_3_s1/Q | g_sound.u_calib1/n909_s/A[1] | clk_sys:[R] | clk_sys:[R] | 17.800 | 0.000 | 13.754
12 | 0.696 | g_sound.u_adc_farm/u_scan0/sample_channel_0_s0/Q | g_sound.u_calib0/n909_s/A[1] | clk_sys:[R] | clk_sys:[R] | 17.800 | 0.008 | 13.716
13 | 0.735 | g_sound.u_adc_farm/u_scan0/sample_channel_0_s0/Q | g_sound.u_calib0/n909_s/A[2] | clk_sys:[R] | clk_sys:[R] | 17.800 | 0.008 | 13.656
14 | 0.752 | g_sound.u_calib_span/cur_axis_o_3_s1/Q | g_sound.u_calib1/n909_s/A[4] | clk_sys:[R] | clk_sys:[R] | 17.800 | 0.000 | 13.754
15 | 0.765 | g_sound.u_fader_gear/gear_o_0_s0/Q | g_sound.u_vibrato_lfo/rate_inc_q_27_s0/D | clk_sys:[R] | clk_sys:[R] | 17.800 | 0.008 | 16.974
16 | 0.792 | g_sound.u_adc_farm/u_scan0/sample_channel_0_s0/Q | g_sound.u_calib0/n909_s/A[7] | clk_sys:[R] | clk_sys:[R] | 17.800 | 0.008 | 13.895
17 | 0.807 | g_sound.u_calib_span/cur_axis_o_3_s1/Q | g_sound.u_calib1/n909_s/A[5] | clk_sys:[R] | clk_sys:[R] | 17.800 | 0.000 | 13.743
18 | 0.827 | g_sound.u_fader_gear/gear_o_0_s0/Q | g_sound.u_vibrato_lfo/rate_inc_q_28_s0/D | clk_sys:[R] | clk_sys:[R] | 17.800 | 0.000 | 16.916
19 | 0.891 | g_sound.u_fader_gear/gear_o_0_s0/Q | g_sound.u_vibrato_lfo/rate_inc_q_9_s0/D | clk_sys:[R] | clk_sys:[R] | 17.800 | 0.000 | 16.852
20 | 0.900 | g_sound.u_adc_farm/u_scan0/sample_channel_0_s0/Q | g_sound.u_calib0/n909_s/A[3] | clk_sys:[R] | clk_sys:[R] | 17.800 | 0.008 | 13.638
21 | 0.918 | g_sound.u_note_manager/scan_cnt_4_s0/Q | g_sound.u_note_manager/best_env_1_s0/CE | clk_sys:[R] | clk_sys:[R] | 17.800 | 0.446 | 16.156
22 | 0.918 | g_sound.u_note_manager/scan_cnt_4_s0/Q | g_sound.u_note_manager/best_env_2_s0/CE | clk_sys:[R] | clk_sys:[R] | 17.800 | 0.446 | 16.156
23 | 0.972 | g_sound.u_fader_gear/gear_o_0_s0/Q | g_sound.u_vibrato_lfo/rate_inc_q_19_s0/D | clk_sys:[R] | clk_sys:[R] | 17.800 | -0.008 | 16.779
24 | 1.085 | g_sound.u_adc_farm/u_scan0/sample_channel_0_s0/Q | g_sound.u_calib0/n909_s/A[4] | clk_sys:[R] | clk_sys:[R] | 17.800 | 0.008 | 13.401
25 | 1.087 | g_sound.u_calib_span/cur_axis_o_3_s1/Q | g_sound.u_calib1/n909_s/A[8] | clk_sys:[R] | clk_sys:[R] | 17.800 | 0.000 | 13.600

### Hold Paths Table

#### Report Command:report_timing -hold -max_paths 25 -max_common_paths 1

Path Number | Path Slack | From Node | To Node | From Clock | To Clock | Relation | Clock Skew | Data Delay
1 | 0.115 | u_rst_sync/sync_chain_1_s0/Q | u_hdmi/rstn_ser_0_s0/RESET | clk_sys:[R] | serial_clk:[R] | 0.000 | -0.920 | 0.985
2 | 0.128 | g_sound.u_looper/rd_ptr_r_9_s0/Q | g_sound.u_looper/ep_mem_ep_mem_0_5_s/ADB[12] | clk_sys:[R] | clk_sys:[R] | 0.000 | -0.185 | 0.344
3 | 0.148 | u_hdmi/u_blue/symbol_7_s0/Q | u_hdmi/u_serializer/lanes[0].u_oser/D7 | pixel_clk:[R] | pixel_clk:[R] | 0.000 | 0.000 | 0.222
4 | 0.198 | g_sound.u_envelope_bank/env_level_o_470_s0/Q | g_sound.u_note_manager/env_level_r_470_s0/D | clk_sys:[R] | clk_sys:[R] | 0.000 | -0.177 | 0.387
5 | 0.202 | g_sound.u_envelope_bank/env_level_o_503_s0/Q | g_sound.u_note_manager/env_level_r_503_s0/D | clk_sys:[R] | clk_sys:[R] | 0.000 | -0.174 | 0.387
6 | 0.204 | g_sound.u_looper/rd_ptr_r_2_s0/Q | g_sound.u_looper/ep_mem_ep_mem_0_4_s/ADB[5] | clk_sys:[R] | clk_sys:[R] | 0.000 | -0.177 | 0.413
7 | 0.207 | u_hdmi/u_blue/symbol_7_s0/Q | u_hdmi/u_serializer/lanes[0].u_oser/D0 | pixel_clk:[R] | pixel_clk:[R] | 0.000 | 0.000 | 0.292
8 | 0.208 | u_hdmi/u_blue/symbol_8_s0/Q | u_hdmi/u_serializer/lanes[0].u_oser/D8 | pixel_clk:[R] | pixel_clk:[R] | 0.000 | 0.007 | 0.286
9 | 0.211 | g_sound.u_envelope_bank/env_level_o_486_s0/Q | g_sound.u_note_manager/env_level_r_486_s0/D | clk_sys:[R] | clk_sys:[R] | 0.000 | -0.174 | 0.396
10 | 0.211 | g_sound.u_looper/rd_ptr_r_9_s0/Q | g_sound.u_looper/ep_mem_ep_mem_0_3_s/ADB[12] | clk_sys:[R] | clk_sys:[R] | 0.000 | -0.177 | 0.420
11 | 0.215 | u_hdmi/u_blue/symbol_7_s0/Q | u_hdmi/u_serializer/lanes[0].u_oser/D5 | pixel_clk:[R] | pixel_clk:[R] | 0.000 | 0.000 | 0.290
12 | 0.218 | u_hdmi/u_blue/symbol_7_s0/Q | u_hdmi/u_serializer/lanes[0].u_oser/D1 | pixel_clk:[R] | pixel_clk:[R] | 0.000 | 0.000 | 0.292
13 | 0.247 | u_led_indicator/beat_t_1_s1/Q | u_led_indicator/beat_t_1_s1/D | clk_sys:[R] | clk_sys:[R] | 0.000 | 0.000 | 0.270
14 | 0.247 | u_led_indicator/beat_t_4_s1/Q | u_led_indicator/beat_t_4_s1/D | clk_sys:[R] | clk_sys:[R] | 0.000 | 0.000 | 0.270
15 | 0.247 | u_led_indicator/beat_t_11_s1/Q | u_led_indicator/beat_t_11_s1/D | clk_sys:[R] | clk_sys:[R] | 0.000 | 0.000 | 0.270
16 | 0.247 | u_led_indicator/beat_t_5_s0/Q | u_led_indicator/beat_t_5_s0/D | clk_sys:[R] | clk_sys:[R] | 0.000 | 0.000 | 0.270
17 | 0.247 | u_ws2812/bit_t_5_s1/Q | u_ws2812/bit_t_5_s1/D | clk_sys:[R] | clk_sys:[R] | 0.000 | 0.000 | 0.270
18 | 0.247 | u_ws2812/bit_i_0_s1/Q | u_ws2812/bit_i_0_s1/D | clk_sys:[R] | clk_sys:[R] | 0.000 | 0.000 | 0.270
19 | 0.247 | u_ws2812/led_i_0_s1/Q | u_ws2812/led_i_0_s1/D | clk_sys:[R] | clk_sys:[R] | 0.000 | 0.000 | 0.270
20 | 0.247 | u_ws2812/rst_t_4_s0/Q | u_ws2812/rst_t_4_s0/D | clk_sys:[R] | clk_sys:[R] | 0.000 | 0.000 | 0.270
21 | 0.247 | u_ws2812/rst_t_8_s0/Q | u_ws2812/rst_t_8_s0/D | clk_sys:[R] | clk_sys:[R] | 0.000 | 0.000 | 0.270
22 | 0.247 | u_ws2812/rst_t_13_s0/Q | u_ws2812/rst_t_13_s0/D | clk_sys:[R] | clk_sys:[R] | 0.000 | 0.000 | 0.270
23 | 0.247 | u_i2s_tx/bit_cnt_4_s0/Q | u_i2s_tx/bit_cnt_4_s0/D | clk_sys:[R] | clk_sys:[R] | 0.000 | 0.000 | 0.270
24 | 0.247 | g_sound.u_tdm_render_mixer/norm_gain_r_13_s0/Q | g_sound.u_tdm_render_mixer/norm_gain_r_13_s0/D | clk_sys:[R] | clk_sys:[R] | 0.000 | 0.000 | 0.270
25 | 0.247 | g_sound.u_perc_env_bank/gen_perc[3].level_r_6_s0/Q | g_sound.u_perc_env_bank/gen_perc[3].level_r_6_s0/D | clk_sys:[R] | clk_sys:[R] | 0.000 | 0.000 | 0.270

### Recovery Paths Table

#### Report Command:report_timing -recovery -max_paths 25 -max_common_paths 1

Path Number | Path Slack | From Node | To Node | From Clock | To Clock | Relation | Clock Skew | Data Delay
1 | 0.086 | u_hdmi/rstn_ser_2_s0/Q | u_hdmi/u_serializer/lanes[3].u_oser/RESET | serial_clk:[R] | serial_clk:[F] | 4.000 | 2.671 | 1.107
2 | 0.094 | u_hdmi/rstn_ser_2_s0/Q | u_hdmi/u_serializer/lanes[0].u_oser/RESET | serial_clk:[R] | serial_clk:[F] | 4.000 | 2.671 | 1.099
3 | 0.165 | u_hdmi/rstn_ser_2_s0/Q | u_hdmi/u_serializer/lanes[1].u_oser/RESET | serial_clk:[R] | serial_clk:[F] | 4.000 | 2.671 | 1.028
4 | 0.170 | u_hdmi/rstn_ser_2_s0/Q | u_hdmi/u_serializer/lanes[2].u_oser/RESET | serial_clk:[R] | serial_clk:[F] | 4.000 | 2.671 | 1.024
5 | 4.085 | u_hdmi/rstn_ser_2_s0/Q | u_hdmi/u_serializer/lanes[3].u_oser/RESET | serial_clk:[R] | serial_clk:[R] | 8.000 | 2.671 | 1.107
6 | 4.092 | u_hdmi/rstn_ser_2_s0/Q | u_hdmi/u_serializer/lanes[0].u_oser/RESET | serial_clk:[R] | serial_clk:[R] | 8.000 | 2.671 | 1.099
7 | 4.163 | u_hdmi/rstn_ser_2_s0/Q | u_hdmi/u_serializer/lanes[1].u_oser/RESET | serial_clk:[R] | serial_clk:[R] | 8.000 | 2.671 | 1.028
8 | 4.168 | u_hdmi/rstn_ser_2_s0/Q | u_hdmi/u_serializer/lanes[2].u_oser/RESET | serial_clk:[R] | serial_clk:[R] | 8.000 | 2.671 | 1.024
9 | 5.931 | u_hdmi/rstn_ser_2_s0/Q | u_hdmi/u_serializer/lanes[3].u_oser/RESET | serial_clk:[R] | pixel_clk:[R] | 8.000 | 0.790 | 1.107
10 | 5.938 | u_hdmi/rstn_ser_2_s0/Q | u_hdmi/u_serializer/lanes[0].u_oser/RESET | serial_clk:[R] | pixel_clk:[R] | 8.000 | 0.790 | 1.099
11 | 6.009 | u_hdmi/rstn_ser_2_s0/Q | u_hdmi/u_serializer/lanes[1].u_oser/RESET | serial_clk:[R] | pixel_clk:[R] | 8.000 | 0.790 | 1.028
12 | 6.014 | u_hdmi/rstn_ser_2_s0/Q | u_hdmi/u_serializer/lanes[2].u_oser/RESET | serial_clk:[R] | pixel_clk:[R] | 8.000 | 0.790 | 1.024

### Removal Paths Table

#### Report Command:report_timing -removal -max_paths 25 -max_common_paths 1

Path Number | Path Slack | From Node | To Node | From Clock | To Clock | Relation | Clock Skew | Data Delay
1 | 0.494 | u_hdmi/rstn_ser_2_s0/Q | u_hdmi/u_serializer/lanes[1].u_oser/RESET | serial_clk:[R] | pixel_clk:[R] | 0.000 | 0.325 | 0.342
2 | 0.498 | u_hdmi/rstn_ser_2_s0/Q | u_hdmi/u_serializer/lanes[2].u_oser/RESET | serial_clk:[R] | pixel_clk:[R] | 0.000 | 0.325 | 0.346
3 | 0.556 | u_hdmi/rstn_ser_2_s0/Q | u_hdmi/u_serializer/lanes[0].u_oser/RESET | serial_clk:[R] | pixel_clk:[R] | 0.000 | 0.325 | 0.404
4 | 0.645 | u_hdmi/rstn_ser_2_s0/Q | u_hdmi/u_serializer/lanes[3].u_oser/RESET | serial_clk:[R] | pixel_clk:[R] | 0.000 | 0.325 | 0.492
5 | 1.131 | u_hdmi/rstn_ser_2_s0/Q | u_hdmi/u_serializer/lanes[1].u_oser/RESET | serial_clk:[R] | serial_clk:[R] | 0.000 | 0.927 | 0.342
6 | 1.135 | u_hdmi/rstn_ser_2_s0/Q | u_hdmi/u_serializer/lanes[2].u_oser/RESET | serial_clk:[R] | serial_clk:[R] | 0.000 | 0.927 | 0.346
7 | 1.193 | u_hdmi/rstn_ser_2_s0/Q | u_hdmi/u_serializer/lanes[0].u_oser/RESET | serial_clk:[R] | serial_clk:[R] | 0.000 | 0.927 | 0.404
8 | 1.282 | u_hdmi/rstn_ser_2_s0/Q | u_hdmi/u_serializer/lanes[3].u_oser/RESET | serial_clk:[R] | serial_clk:[R] | 0.000 | 0.927 | 0.492
9 | 5.133 | u_hdmi/rstn_ser_2_s0/Q | u_hdmi/u_serializer/lanes[1].u_oser/RESET | serial_clk:[R] | serial_clk:[F] | -4.000 | 0.927 | 0.342
10 | 5.137 | u_hdmi/rstn_ser_2_s0/Q | u_hdmi/u_serializer/lanes[2].u_oser/RESET | serial_clk:[R] | serial_clk:[F] | -4.000 | 0.927 | 0.346
11 | 5.195 | u_hdmi/rstn_ser_2_s0/Q | u_hdmi/u_serializer/lanes[0].u_oser/RESET | serial_clk:[R] | serial_clk:[F] | -4.000 | 0.927 | 0.404
12 | 5.283 | u_hdmi/rstn_ser_2_s0/Q | u_hdmi/u_serializer/lanes[3].u_oser/RESET | serial_clk:[R] | serial_clk:[F] | -4.000 | 0.927 | 0.492

## Minimum Pulse Width Table:

Number | Slack | Actual Width | Required Width | Type | Clock | Objects

#### Report Command:report_min_pulse_width -nworst 10 -detail

1 | 0.087 | 0.312 | 0.225 | Low Pulse Width | serial_clk | u_hdmi/rstn_ser_2_s0
2 | 0.087 | 0.312 | 0.225 | Low Pulse Width | serial_clk | u_hdmi/rstn_ser_1_s0
3 | 0.087 | 0.312 | 0.225 | Low Pulse Width | serial_clk | u_hdmi/rstn_ser_0_s0
4 | 0.088 | 0.313 | 0.225 | High Pulse Width | serial_clk | u_hdmi/rstn_ser_2_s0
5 | 0.088 | 0.313 | 0.225 | High Pulse Width | serial_clk | u_hdmi/rstn_ser_1_s0
6 | 0.088 | 0.313 | 0.225 | High Pulse Width | serial_clk | u_hdmi/rstn_ser_0_s0
7 | 6.809 | 7.709 | 0.900 | Low Pulse Width | clk_sys | g_sound.u_looper/mem_mem_0_7_s
8 | 6.809 | 7.709 | 0.900 | Low Pulse Width | clk_sys | g_sound.u_looper/ep_mem_ep_mem_0_0_s
9 | 6.809 | 7.709 | 0.900 | Low Pulse Width | clk_sys | g_sound.u_looper/ep_mem_ep_mem_0_1_s
10 | 6.809 | 7.709 | 0.900 | Low Pulse Width | clk_sys | g_sound.u_looper/ep_mem_ep_mem_0_4_s

## Timing Report By Analysis Type:

### Setup Analysis Report

#### Report Command:report_timing -setup -max_paths 25 -max_common_paths 1

### Path1

Path Summary:

Slack | 0.306
Data Arrival Time | 21.570
Data Required Time | 21.876
From | g_sound.u_fader_gear/gear_o_0_s0
To | g_sound.u_vibrato_lfo/rate_inc_q_25_s0
Launch Clk | clk_sys:[R]
Latch Clk | clk_sys:[R]

Data Arrival Path:

AT | DELAY | TYPE | RF | FANOUT | LOC | NODE
0.000 | 0.000 | | | | | active clock edge time
0.000 | 0.000 | | | | | clk_sys
0.000 | 0.000 | tCL | RR | 1 | IOB117[B] | clk_ibuf/I
1.288 | 1.288 | tINS | RR | 17287 | IOB117[B] | clk_ibuf/O
4.142 | 2.854 | tNET | RR | 1 | R60C109[0][A] | g_sound.u_fader_gear/gear_o_0_s0/CLK
4.486 | 0.344 | tC2Q | RR | 23 | R60C109[0][A] | g_sound.u_fader_gear/gear_o_0_s0/Q
6.011 | 1.524 | tNET | RR | 1 | R66C119[3][B] | g_sound.u_fader_gear/g_sound.vib_rate_sel_0_s/I0
6.458 | 0.448 | tINS | RR | 1 | R66C119[3][B] | g_sound.u_fader_gear/g_sound.vib_rate_sel_0_s/F
7.519 | 1.061 | tNET | RR | 97 | DSP_R65[31] | g_sound.u_vibrato_lfo/rate_product_0_s/A[0]
10.176 | 2.657 | tINS | RR | 3 | DSP_R65[31] | g_sound.u_vibrato_lfo/rate_product_0_s/DOUT[15]
11.142 | 0.966 | tNET | RR | 1 | R68C116[0][A] | g_sound.u_vibrato_lfo/rate_target_w_5_s3/I2
11.607 | 0.465 | tINS | RR | 3 | R68C116[0][A] | g_sound.u_vibrato_lfo/rate_target_w_5_s3/F
11.753 | 0.146 | tNET | RR | 1 | R69C116[2][B] | g_sound.u_vibrato_lfo/rate_target_w_8_s3/I0
12.218 | 0.465 | tINS | RR | 4 | R69C116[2][B] | g_sound.u_vibrato_lfo/rate_target_w_8_s3/F
12.537 | 0.319 | tNET | RR | 1 | R68C117[2][A] | g_sound.u_vibrato_lfo/rate_target_w_9_s2/I1
13.002 | 0.465 | tINS | RR | 8 | R68C117[2][A] | g_sound.u_vibrato_lfo/rate_target_w_9_s2/F
13.614 | 0.612 | tNET | RR | 2 | R71C116[1][B] | g_sound.u_vibrato_lfo/n462_s/I0
14.114 | 0.501 | tINS | RF | 1 | R71C116[1][B] | g_sound.u_vibrato_lfo/n462_s/COUT
14.114 | 0.000 | tNET | FF | 2 | R71C116[2][A] | g_sound.u_vibrato_lfo/n461_s/CIN
14.159 | 0.045 | tINS | FR | 1 | R71C116[2][A] | g_sound.u_vibrato_lfo/n461_s/COUT
14.159 | 0.000 | tNET | RR | 2 | R71C116[2][B] | g_sound.u_vibrato_lfo/n460_s/CIN
14.204 | 0.045 | tINS | RR | 1 | R71C116[2][B] | g_sound.u_vibrato_lfo/n460_s/COUT
14.204 | 0.000 | tNET | RR | 2 | R71C117[0][A] | g_sound.u_vibrato_lfo/n459_s/CIN
14.249 | 0.045 | tINS | RR | 1 | R71C117[0][A] | g_sound.u_vibrato_lfo/n459_s/COUT
14.249 | 0.000 | tNET | RR | 2 | R71C117[0][B] | g_sound.u_vibrato_lfo/n458_s/CIN
14.294 | 0.045 | tINS | RR | 1 | R71C117[0][B] | g_sound.u_vibrato_lfo/n458_s/COUT
14.294 | 0.000 | tNET | RR | 2 | R71C117[1][A] | g_sound.u_vibrato_lfo/n457_s/CIN
14.339 | 0.045 | tINS | RR | 1 | R71C117[1][A] | g_sound.u_vibrato_lfo/n457_s/COUT
14.339 | 0.000 | tNET | RR | 2 | R71C117[1][B] | g_sound.u_vibrato_lfo/n456_s/CIN
14.384 | 0.045 | tINS | RR | 1 | R71C117[1][B] | g_sound.u_vibrato_lfo/n456_s/COUT
14.384 | 0.000 | tNET | RR | 2 | R71C117[2][A] | g_sound.u_vibrato_lfo/n455_s/CIN
14.429 | 0.045 | tINS | RR | 1 | R71C117[2][A] | g_sound.u_vibrato_lfo/n455_s/COUT
14.429 | 0.000 | tNET | RR | 2 | R71C117[2][B] | g_sound.u_vibrato_lfo/n454_s/CIN
14.474 | 0.045 | tINS | RR | 1 | R71C117[2][B] | g_sound.u_vibrato_lfo/n454_s/COUT
14.474 | 0.000 | tNET | RR | 2 | R71C118[0][A] | g_sound.u_vibrato_lfo/n453_s/CIN
14.519 | 0.045 | tINS | RR | 1 | R71C118[0][A] | g_sound.u_vibrato_lfo/n453_s/COUT
14.519 | 0.000 | tNET | RR | 2 | R71C118[0][B] | g_sound.u_vibrato_lfo/n452_s/CIN
14.564 | 0.045 | tINS | RR | 1 | R71C118[0][B] | g_sound.u_vibrato_lfo/n452_s/COUT
14.564 | 0.000 | tNET | RR | 2 | R71C118[1][A] | g_sound.u_vibrato_lfo/n451_s/CIN
14.609 | 0.045 | tINS | RR | 1 | R71C118[1][A] | g_sound.u_vibrato_lfo/n451_s/COUT
14.609 | 0.000 | tNET | RR | 2 | R71C118[1][B] | g_sound.u_vibrato_lfo/n450_s/CIN
14.654 | 0.045 | tINS | RR | 1 | R71C118[1][B] | g_sound.u_vibrato_lfo/n450_s/COUT
14.654 | 0.000 | tNET | RR | 2 | R71C118[2][A] | g_sound.u_vibrato_lfo/n449_s/CIN
14.699 | 0.045 | tINS | RR | 1 | R71C118[2][A] | g_sound.u_vibrato_lfo/n449_s/COUT
14.699 | 0.000 | tNET | RR | 2 | R71C118[2][B] | g_sound.u_vibrato_lfo/n448_s/CIN
14.970 | 0.271 | tINS | RF | 1 | R71C118[2][B] | g_sound.u_vibrato_lfo/n448_s/SUM
14.975 | 0.005 | tNET | FF | 1 | R71C118[3][A] | g_sound.u_vibrato_lfo/n651_s19/I1
15.423 | 0.448 | tINS | FR | 1 | R71C118[3][A] | g_sound.u_vibrato_lfo/n651_s19/F
15.425 | 0.002 | tNET | RR | 1 | R71C118[3][B] | g_sound.u_vibrato_lfo/n651_s18/I3
15.798 | 0.373 | tINS | RR | 1 | R71C118[3][B] | g_sound.u_vibrato_lfo/n651_s18/F
16.111 | 0.313 | tNET | RR | 1 | R72C116[0][B] | g_sound.u_vibrato_lfo/n651_s15/I3
16.526 | 0.415 | tINS | RR | 1 | R72C116[0][B] | g_sound.u_vibrato_lfo/n651_s15/F
16.821 | 0.295 | tNET | RR | 1 | R71C116[3][A] | g_sound.u_vibrato_lfo/n651_s11/I3
17.290 | 0.469 | tINS | RR | 1 | R71C116[3][A] | g_sound.u_vibrato_lfo/n651_s11/F
17.657 | 0.367 | tNET | RR | 1 | R71C119[3][B] | g_sound.u_vibrato_lfo/n651_s7/I3
18.105 | 0.448 | tINS | RR | 4 | R71C119[3][B] | g_sound.u_vibrato_lfo/n651_s7/F
18.820 | 0.715 | tNET | RR | 1 | R72C115[1][B] | g_sound.u_vibrato_lfo/n651_s2/I0
19.294 | 0.474 | tINS | RR | 19 | R72C115[1][B] | g_sound.u_vibrato_lfo/n651_s2/F
21.105 | 1.811 | tNET | RR | 1 | R71C122[1][A] | g_sound.u_vibrato_lfo/n668_s0/I0
21.570 | 0.465 | tINS | RR | 1 | R71C122[1][A] | g_sound.u_vibrato_lfo/n668_s0/F
21.570 | 0.000 | tNET | RR | 1 | R71C122[1][A] | g_sound.u_vibrato_lfo/rate_inc_q_25_s0/D

Data Required Path:

AT | DELAY | TYPE | RF | FANOUT | LOC | NODE
17.800 | 17.800 | | | | | active clock edge time
17.800 | 0.000 | | | | | clk_sys
17.800 | 0.000 | tCL | RR | 1 | IOB117[B] | clk_ibuf/I
19.088 | 1.288 | tINS | RR | 17287 | IOB117[B] | clk_ibuf/O
21.933 | 2.845 | tNET | RR | 1 | R71C122[1][A] | g_sound.u_vibrato_lfo/rate_inc_q_25_s0/CLK
21.876 | -0.057 | tSu | | 1 | R71C122[1][A] | g_sound.u_vibrato_lfo/rate_inc_q_25_s0

Path Statistics:

Clock Skew | -0.008
Setup Relationship | 17.800
Logic Level | 16
Arrival Clock Path Delay | cell: 1.288, 31.105%; route: 2.854, 68.895%
Arrival Data Path Delay | cell: 8.946, 51.334%; route: 8.137, 46.691%; tC2Q: 0.344, 1.975%
Required Clock Path Delay | cell: 1.288, 31.169%; route: 2.845, 68.831%

### Path2

Path Summary:

Slack | 0.315
Data Arrival Time | 21.570
Data Required Time | 21.885
From | g_sound.u_fader_gear/gear_o_0_s0
To | g_sound.u_vibrato_lfo/rate_inc_q_10_s0
Launch Clk | clk_sys:[R]
Latch Clk | clk_sys:[R]

Data Arrival Path:

AT | DELAY | TYPE | RF | FANOUT | LOC | NODE
0.000 | 0.000 | | | | | active clock edge time
0.000 | 0.000 | | | | | clk_sys
0.000 | 0.000 | tCL | RR | 1 | IOB117[B] | clk_ibuf/I
1.288 | 1.288 | tINS | RR | 17287 | IOB117[B] | clk_ibuf/O
4.142 | 2.854 | tNET | RR | 1 | R60C109[0][A] | g_sound.u_fader_gear/gear_o_0_s0/CLK
4.486 | 0.344 | tC2Q | RR | 23 | R60C109[0][A] | g_sound.u_fader_gear/gear_o_0_s0/Q
6.011 | 1.524 | tNET | RR | 1 | R66C119[3][B] | g_sound.u_fader_gear/g_sound.vib_rate_sel_0_s/I0
6.458 | 0.448 | tINS | RR | 1 | R66C119[3][B] | g_sound.u_fader_gear/g_sound.vib_rate_sel_0_s/F
7.519 | 1.061 | tNET | RR | 97 | DSP_R65[31] | g_sound.u_vibrato_lfo/rate_product_0_s/A[0]
10.176 | 2.657 | tINS | RR | 3 | DSP_R65[31] | g_sound.u_vibrato_lfo/rate_product_0_s/DOUT[15]
11.142 | 0.966 | tNET | RR | 1 | R68C116[0][A] | g_sound.u_vibrato_lfo/rate_target_w_5_s3/I2
11.607 | 0.465 | tINS | RR | 3 | R68C116[0][A] | g_sound.u_vibrato_lfo/rate_target_w_5_s3/F
11.753 | 0.146 | tNET | RR | 1 | R69C116[2][B] | g_sound.u_vibrato_lfo/rate_target_w_8_s3/I0
12.218 | 0.465 | tINS | RR | 4 | R69C116[2][B] | g_sound.u_vibrato_lfo/rate_target_w_8_s3/F
12.537 | 0.319 | tNET | RR | 1 | R68C117[2][A] | g_sound.u_vibrato_lfo/rate_target_w_9_s2/I1
13.002 | 0.465 | tINS | RR | 8 | R68C117[2][A] | g_sound.u_vibrato_lfo/rate_target_w_9_s2/F
13.614 | 0.612 | tNET | RR | 2 | R71C116[1][B] | g_sound.u_vibrato_lfo/n462_s/I0
14.114 | 0.501 | tINS | RF | 1 | R71C116[1][B] | g_sound.u_vibrato_lfo/n462_s/COUT
14.114 | 0.000 | tNET | FF | 2 | R71C116[2][A] | g_sound.u_vibrato_lfo/n461_s/CIN
14.159 | 0.045 | tINS | FR | 1 | R71C116[2][A] | g_sound.u_vibrato_lfo/n461_s/COUT
14.159 | 0.000 | tNET | RR | 2 | R71C116[2][B] | g_sound.u_vibrato_lfo/n460_s/CIN
14.204 | 0.045 | tINS | RR | 1 | R71C116[2][B] | g_sound.u_vibrato_lfo/n460_s/COUT
14.204 | 0.000 | tNET | RR | 2 | R71C117[0][A] | g_sound.u_vibrato_lfo/n459_s/CIN
14.249 | 0.045 | tINS | RR | 1 | R71C117[0][A] | g_sound.u_vibrato_lfo/n459_s/COUT
14.249 | 0.000 | tNET | RR | 2 | R71C117[0][B] | g_sound.u_vibrato_lfo/n458_s/CIN
14.294 | 0.045 | tINS | RR | 1 | R71C117[0][B] | g_sound.u_vibrato_lfo/n458_s/COUT
14.294 | 0.000 | tNET | RR | 2 | R71C117[1][A] | g_sound.u_vibrato_lfo/n457_s/CIN
14.339 | 0.045 | tINS | RR | 1 | R71C117[1][A] | g_sound.u_vibrato_lfo/n457_s/COUT
14.339 | 0.000 | tNET | RR | 2 | R71C117[1][B] | g_sound.u_vibrato_lfo/n456_s/CIN
14.384 | 0.045 | tINS | RR | 1 | R71C117[1][B] | g_sound.u_vibrato_lfo/n456_s/COUT
14.384 | 0.000 | tNET | RR | 2 | R71C117[2][A] | g_sound.u_vibrato_lfo/n455_s/CIN
14.429 | 0.045 | tINS | RR | 1 | R71C117[2][A] | g_sound.u_vibrato_lfo/n455_s/COUT
14.429 | 0.000 | tNET | RR | 2 | R71C117[2][B] | g_sound.u_vibrato_lfo/n454_s/CIN
14.474 | 0.045 | tINS | RR | 1 | R71C117[2][B] | g_sound.u_vibrato_lfo/n454_s/COUT
14.474 | 0.000 | tNET | RR | 2 | R71C118[0][A] | g_sound.u_vibrato_lfo/n453_s/CIN
14.519 | 0.045 | tINS | RR | 1 | R71C118[0][A] | g_sound.u_vibrato_lfo/n453_s/COUT
14.519 | 0.000 | tNET | RR | 2 | R71C118[0][B] | g_sound.u_vibrato_lfo/n452_s/CIN
14.564 | 0.045 | tINS | RR | 1 | R71C118[0][B] | g_sound.u_vibrato_lfo/n452_s/COUT
14.564 | 0.000 | tNET | RR | 2 | R71C118[1][A] | g_sound.u_vibrato_lfo/n451_s/CIN
14.609 | 0.045 | tINS | RR | 1 | R71C118[1][A] | g_sound.u_vibrato_lfo/n451_s/COUT
14.609 | 0.000 | tNET | RR | 2 | R71C118[1][B] | g_sound.u_vibrato_lfo/n450_s/CIN
14.654 | 0.045 | tINS | RR | 1 | R71C118[1][B] | g_sound.u_vibrato_lfo/n450_s/COUT
14.654 | 0.000 | tNET | RR | 2 | R71C118[2][A] | g_sound.u_vibrato_lfo/n449_s/CIN
14.699 | 0.045 | tINS | RR | 1 | R71C118[2][A] | g_sound.u_vibrato_lfo/n449_s/COUT
14.699 | 0.000 | tNET | RR | 2 | R71C118[2][B] | g_sound.u_vibrato_lfo/n448_s/CIN
14.970 | 0.271 | tINS | RF | 1 | R71C118[2][B] | g_sound.u_vibrato_lfo/n448_s/SUM
14.975 | 0.005 | tNET | FF | 1 | R71C118[3][A] | g_sound.u_vibrato_lfo/n651_s19/I1
15.423 | 0.448 | tINS | FR | 1 | R71C118[3][A] | g_sound.u_vibrato_lfo/n651_s19/F
15.425 | 0.002 | tNET | RR | 1 | R71C118[3][B] | g_sound.u_vibrato_lfo/n651_s18/I3
15.798 | 0.373 | tINS | RR | 1 | R71C118[3][B] | g_sound.u_vibrato_lfo/n651_s18/F
16.111 | 0.313 | tNET | RR | 1 | R72C116[0][B] | g_sound.u_vibrato_lfo/n651_s15/I3
16.526 | 0.415 | tINS | RR | 1 | R72C116[0][B] | g_sound.u_vibrato_lfo/n651_s15/F
16.821 | 0.295 | tNET | RR | 1 | R71C116[3][A] | g_sound.u_vibrato_lfo/n651_s11/I3
17.290 | 0.469 | tINS | RR | 1 | R71C116[3][A] | g_sound.u_vibrato_lfo/n651_s11/F
17.657 | 0.367 | tNET | RR | 1 | R71C119[3][B] | g_sound.u_vibrato_lfo/n651_s7/I3
18.105 | 0.448 | tINS | RR | 4 | R71C119[3][B] | g_sound.u_vibrato_lfo/n651_s7/F
18.820 | 0.715 | tNET | RR | 1 | R72C115[1][B] | g_sound.u_vibrato_lfo/n651_s2/I0
19.294 | 0.474 | tINS | RR | 19 | R72C115[1][B] | g_sound.u_vibrato_lfo/n651_s2/F
21.105 | 1.811 | tNET | RR | 1 | R71C121[0][A] | g_sound.u_vibrato_lfo/n651_s0/I3
21.570 | 0.465 | tINS | RR | 1 | R71C121[0][A] | g_sound.u_vibrato_lfo/n651_s0/F
21.570 | 0.000 | tNET | RR | 1 | R71C121[0][A] | g_sound.u_vibrato_lfo/rate_inc_q_10_s0/D

Data Required Path:

AT | DELAY | TYPE | RF | FANOUT | LOC | NODE
17.800 | 17.800 | | | | | active clock edge time
17.800 | 0.000 | | | | | clk_sys
17.800 | 0.000 | tCL | RR | 1 | IOB117[B] | clk_ibuf/I
19.088 | 1.288 | tINS | RR | 17287 | IOB117[B] | clk_ibuf/O
21.942 | 2.854 | tNET | RR | 1 | R71C121[0][A] | g_sound.u_vibrato_lfo/rate_inc_q_10_s0/CLK
21.885 | -0.057 | tSu | | 1 | R71C121[0][A] | g_sound.u_vibrato_lfo/rate_inc_q_10_s0

Path Statistics:

Clock Skew | 0.000
Setup Relationship | 17.800
Logic Level | 16
Arrival Clock Path Delay | cell: 1.288, 31.105%; route: 2.854, 68.895%
Arrival Data Path Delay | cell: 8.946, 51.334%; route: 8.137, 46.691%; tC2Q: 0.344, 1.975%
Required Clock Path Delay | cell: 1.288, 31.105%; route: 2.854, 68.895%

### Path3

Path Summary:

Slack | 0.394
Data Arrival Time | 21.488
Data Required Time | 21.882
From | g_sound.u_fader_gear/gear_o_0_s0
To | g_sound.u_vibrato_lfo/rate_inc_q_13_s0
Launch Clk | clk_sys:[R]
Latch Clk | clk_sys:[R]

Data Arrival Path:

AT | DELAY | TYPE | RF | FANOUT | LOC | NODE
0.000 | 0.000 | | | | | active clock edge time
0.000 | 0.000 | | | | | clk_sys
0.000 | 0.000 | tCL | RR | 1 | IOB117[B] | clk_ibuf/I
1.288 | 1.288 | tINS | RR | 17287 | IOB117[B] | clk_ibuf/O
4.142 | 2.854 | tNET | RR | 1 | R60C109[0][A] | g_sound.u_fader_gear/gear_o_0_s0/CLK
4.486 | 0.344 | tC2Q | RR | 23 | R60C109[0][A] | g_sound.u_fader_gear/gear_o_0_s0/Q
6.011 | 1.524 | tNET | RR | 1 | R66C119[3][B] | g_sound.u_fader_gear/g_sound.vib_rate_sel_0_s/I0
6.458 | 0.448 | tINS | RR | 1 | R66C119[3][B] | g_sound.u_fader_gear/g_sound.vib_rate_sel_0_s/F
7.519 | 1.061 | tNET | RR | 97 | DSP_R65[31] | g_sound.u_vibrato_lfo/rate_product_0_s/A[0]
10.176 | 2.657 | tINS | RR | 3 | DSP_R65[31] | g_sound.u_vibrato_lfo/rate_product_0_s/DOUT[15]
11.142 | 0.966 | tNET | RR | 1 | R68C116[0][A] | g_sound.u_vibrato_lfo/rate_target_w_5_s3/I2
11.607 | 0.465 | tINS | RR | 3 | R68C116[0][A] | g_sound.u_vibrato_lfo/rate_target_w_5_s3/F
11.753 | 0.146 | tNET | RR | 1 | R69C116[2][B] | g_sound.u_vibrato_lfo/rate_target_w_8_s3/I0
12.218 | 0.465 | tINS | RR | 4 | R69C116[2][B] | g_sound.u_vibrato_lfo/rate_target_w_8_s3/F
12.537 | 0.319 | tNET | RR | 1 | R68C117[2][A] | g_sound.u_vibrato_lfo/rate_target_w_9_s2/I1
13.002 | 0.465 | tINS | RR | 8 | R68C117[2][A] | g_sound.u_vibrato_lfo/rate_target_w_9_s2/F
13.614 | 0.612 | tNET | RR | 2 | R71C116[1][B] | g_sound.u_vibrato_lfo/n462_s/I0
14.114 | 0.501 | tINS | RF | 1 | R71C116[1][B] | g_sound.u_vibrato_lfo/n462_s/COUT
14.114 | 0.000 | tNET | FF | 2 | R71C116[2][A] | g_sound.u_vibrato_lfo/n461_s/CIN
14.159 | 0.045 | tINS | FR | 1 | R71C116[2][A] | g_sound.u_vibrato_lfo/n461_s/COUT
14.159 | 0.000 | tNET | RR | 2 | R71C116[2][B] | g_sound.u_vibrato_lfo/n460_s/CIN
14.204 | 0.045 | tINS | RR | 1 | R71C116[2][B] | g_sound.u_vibrato_lfo/n460_s/COUT
14.204 | 0.000 | tNET | RR | 2 | R71C117[0][A] | g_sound.u_vibrato_lfo/n459_s/CIN
14.249 | 0.045 | tINS | RR | 1 | R71C117[0][A] | g_sound.u_vibrato_lfo/n459_s/COUT
14.249 | 0.000 | tNET | RR | 2 | R71C117[0][B] | g_sound.u_vibrato_lfo/n458_s/CIN
14.294 | 0.045 | tINS | RR | 1 | R71C117[0][B] | g_sound.u_vibrato_lfo/n458_s/COUT
14.294 | 0.000 | tNET | RR | 2 | R71C117[1][A] | g_sound.u_vibrato_lfo/n457_s/CIN
14.339 | 0.045 | tINS | RR | 1 | R71C117[1][A] | g_sound.u_vibrato_lfo/n457_s/COUT
14.339 | 0.000 | tNET | RR | 2 | R71C117[1][B] | g_sound.u_vibrato_lfo/n456_s/CIN
14.384 | 0.045 | tINS | RR | 1 | R71C117[1][B] | g_sound.u_vibrato_lfo/n456_s/COUT
14.384 | 0.000 | tNET | RR | 2 | R71C117[2][A] | g_sound.u_vibrato_lfo/n455_s/CIN
14.429 | 0.045 | tINS | RR | 1 | R71C117[2][A] | g_sound.u_vibrato_lfo/n455_s/COUT
14.429 | 0.000 | tNET | RR | 2 | R71C117[2][B] | g_sound.u_vibrato_lfo/n454_s/CIN
14.474 | 0.045 | tINS | RR | 1 | R71C117[2][B] | g_sound.u_vibrato_lfo/n454_s/COUT
14.474 | 0.000 | tNET | RR | 2 | R71C118[0][A] | g_sound.u_vibrato_lfo/n453_s/CIN
14.519 | 0.045 | tINS | RR | 1 | R71C118[0][A] | g_sound.u_vibrato_lfo/n453_s/COUT
14.519 | 0.000 | tNET | RR | 2 | R71C118[0][B] | g_sound.u_vibrato_lfo/n452_s/CIN
14.564 | 0.045 | tINS | RR | 1 | R71C118[0][B] | g_sound.u_vibrato_lfo/n452_s/COUT
14.564 | 0.000 | tNET | RR | 2 | R71C118[1][A] | g_sound.u_vibrato_lfo/n451_s/CIN
14.609 | 0.045 | tINS | RR | 1 | R71C118[1][A] | g_sound.u_vibrato_lfo/n451_s/COUT
14.609 | 0.000 | tNET | RR | 2 | R71C118[1][B] | g_sound.u_vibrato_lfo/n450_s/CIN
14.654 | 0.045 | tINS | RR | 1 | R71C118[1][B] | g_sound.u_vibrato_lfo/n450_s/COUT
14.654 | 0.000 | tNET | RR | 2 | R71C118[2][A] | g_sound.u_vibrato_lfo/n449_s/CIN
14.699 | 0.045 | tINS | RR | 1 | R71C118[2][A] | g_sound.u_vibrato_lfo/n449_s/COUT
14.699 | 0.000 | tNET | RR | 2 | R71C118[2][B] | g_sound.u_vibrato_lfo/n448_s/CIN
14.970 | 0.271 | tINS | RF | 1 | R71C118[2][B] | g_sound.u_vibrato_lfo/n448_s/SUM
14.975 | 0.005 | tNET | FF | 1 | R71C118[3][A] | g_sound.u_vibrato_lfo/n651_s19/I1
15.423 | 0.448 | tINS | FR | 1 | R71C118[3][A] | g_sound.u_vibrato_lfo/n651_s19/F
15.425 | 0.002 | tNET | RR | 1 | R71C118[3][B] | g_sound.u_vibrato_lfo/n651_s18/I3
15.798 | 0.373 | tINS | RR | 1 | R71C118[3][B] | g_sound.u_vibrato_lfo/n651_s18/F
16.111 | 0.313 | tNET | RR | 1 | R72C116[0][B] | g_sound.u_vibrato_lfo/n651_s15/I3
16.526 | 0.415 | tINS | RR | 1 | R72C116[0][B] | g_sound.u_vibrato_lfo/n651_s15/F
16.821 | 0.295 | tNET | RR | 1 | R71C116[3][A] | g_sound.u_vibrato_lfo/n651_s11/I3
17.290 | 0.469 | tINS | RR | 1 | R71C116[3][A] | g_sound.u_vibrato_lfo/n651_s11/F
17.657 | 0.367 | tNET | RR | 1 | R71C119[3][B] | g_sound.u_vibrato_lfo/n651_s7/I3
18.105 | 0.448 | tINS | RR | 4 | R71C119[3][B] | g_sound.u_vibrato_lfo/n651_s7/F
18.820 | 0.715 | tNET | RR | 1 | R72C115[1][B] | g_sound.u_vibrato_lfo/n651_s2/I0
19.294 | 0.474 | tINS | RR | 19 | R72C115[1][B] | g_sound.u_vibrato_lfo/n651_s2/F
21.227 | 1.933 | tNET | RR | 1 | R71C122[3][A] | g_sound.u_vibrato_lfo/n680_s0/I0
21.488 | 0.261 | tINS | RF | 1 | R71C122[3][A] | g_sound.u_vibrato_lfo/n680_s0/F
21.488 | 0.000 | tNET | FF | 1 | R71C122[3][A] | g_sound.u_vibrato_lfo/rate_inc_q_13_s0/D

Data Required Path:

AT | DELAY | TYPE | RF | FANOUT | LOC | NODE
17.800 | 17.800 | | | | | active clock edge time
17.800 | 0.000 | | | | | clk_sys
17.800 | 0.000 | tCL | RR | 1 | IOB117[B] | clk_ibuf/I
19.088 | 1.288 | tINS | RR | 17287 | IOB117[B] | clk_ibuf/O
21.933 | 2.845 | tNET | RR | 1 | R71C122[3][A] | g_sound.u_vibrato_lfo/rate_inc_q_13_s0/CLK
21.882 | -0.052 | tSu | | 1 | R71C122[3][A] | g_sound.u_vibrato_lfo/rate_inc_q_13_s0

Path Statistics:

Clock Skew | -0.008
Setup Relationship | 17.800
Logic Level | 16
Arrival Clock Path Delay | cell: 1.288, 31.105%; route: 2.854, 68.895%
Arrival Data Path Delay | cell: 8.743, 50.403%; route: 8.259, 47.612%; tC2Q: 0.344, 1.985%
Required Clock Path Delay | cell: 1.288, 31.169%; route: 2.845, 68.831%

### Path4

Path Summary:

Slack | 0.556
Data Arrival Time | 17.927
Data Required Time | 18.482
From | g_sound.u_calib_span/cur_axis_o_3_s1
To | g_sound.u_calib1/n909_s
Launch Clk | clk_sys:[R]
Latch Clk | clk_sys:[R]

Data Arrival Path:

AT | DELAY | TYPE | RF | FANOUT | LOC | NODE
0.000 | 0.000 | | | | | active clock edge time
0.000 | 0.000 | | | | | clk_sys
0.000 | 0.000 | tCL | RR | 1 | IOB117[B] | clk_ibuf/I
1.288 | 1.288 | tINS | RR | 17287 | IOB117[B] | clk_ibuf/O
4.142 | 2.854 | tNET | RR | 1 | R58C113[0][B] | g_sound.u_calib_span/cur_axis_o_3_s1/CLK
4.473 | 0.331 | tC2Q | RF | 74 | R58C113[0][B] | g_sound.u_calib_span/cur_axis_o_3_s1/Q
6.570 | 2.097 | tNET | FF | 1 | R58C104[0][A] | n4583_s1/I2
7.034 | 0.465 | tINS | FR | 13 | R58C104[0][A] | n4583_s1/F
10.921 | 3.887 | tNET | RR | 1 | R70C43[3][A] | g_sound.u_calib1/dclamp_7_s26/I2
11.182 | 0.261 | tINS | RF | 1 | R70C43[3][A] | g_sound.u_calib1/dclamp_7_s26/F
11.310 | 0.128 | tNET | FF | 1 | R69C43[3][A] | g_sound.u_calib1/dclamp_7_s18/I3
11.684 | 0.373 | tINS | FR | 1 | R69C43[3][A] | g_sound.u_calib1/dclamp_7_s18/F
11.826 | 0.142 | tNET | RR | 1 | R68C43[2][B] | g_sound.u_calib1/dclamp_7_s16/I3
12.299 | 0.474 | tINS | RR | 1 | R68C43[2][B] | g_sound.u_calib1/dclamp_7_s16/F
12.302 | 0.002 | tNET | RR | 1 | R68C43[3][B] | g_sound.u_calib1/dclamp_7_s21/I0
12.749 | 0.448 | tINS | RR | 1 | R68C43[3][B] | g_sound.u_calib1/dclamp_7_s21/F
12.891 | 0.142 | tNET | RR | 1 | R68C44[1][B] | g_sound.u_calib1/dclamp_7_s10/I1
13.306 | 0.415 | tINS | RR | 2 | R68C44[1][B] | g_sound.u_calib1/dclamp_7_s10/F
13.311 | 0.005 | tNET | RR | 1 | R68C44[1][A] | g_sound.u_calib1/dclamp_7_s6/I0
13.775 | 0.465 | tINS | RR | 2 | R68C44[1][A] | g_sound.u_calib1/dclamp_7_s6/F
14.212 | 0.436 | tNET | RR | 1 | R70C43[2][B] | g_sound.u_calib1/dclamp_7_s4/I1
14.676 | 0.465 | tINS | RR | 3 | R70C43[2][B] | g_sound.u_calib1/dclamp_7_s4/F
14.823 | 0.146 | tNET | RR | 1 | R70C42[2][B] | g_sound.u_calib1/dclamp_8_s9/I3
15.296 | 0.474 | tINS | RR | 1 | R70C42[2][B] | g_sound.u_calib1/dclamp_8_s9/F
15.438 | 0.142 | tNET | RR | 1 | R70C43[0][A] | g_sound.u_calib1/dclamp_8_s7/I1
15.853 | 0.415 | tINS | RR | 2 | R70C43[0][A] | g_sound.u_calib1/dclamp_8_s7/F
15.997 | 0.144 | tNET | RR | 1 | R70C44[2][B] | g_sound.u_calib1/dclamp_8_s4/I1
16.462 | 0.465 | tINS | RR | 9 | R70C44[2][B] | g_sound.u_calib1/dclamp_8_s4/F
16.910 | 0.448 | tNET | RR | 1 | R71C43[3][A] | g_sound.u_calib1/dclamp_0_s0/I3
17.357 | 0.448 | tINS | RR | 1 | R71C43[3][A] | g_sound.u_calib1/dclamp_0_s0/F
17.927 | 0.569 | tNET | RR | 1 | DSP_R65[13] | g_sound.u_calib1/n909_s/A[0]

Data Required Path:

AT | DELAY | TYPE | RF | FANOUT | LOC | NODE
17.800 | 17.800 | | | | | active clock edge time
17.800 | 0.000 | | | | | clk_sys
17.800 | 0.000 | tCL | RR | 1 | IOB117[B] | clk_ibuf/I
19.088 | 1.288 | tINS | RR | 17287 | IOB117[B] | clk_ibuf/O
21.942 | 2.854 | tNET | RR | 1 | DSP_R65[13] | g_sound.u_calib1/n909_s/CLK[0]
18.482 | -3.459 | tSu | | 1 | DSP_R65[13] | g_sound.u_calib1/n909_s

Path Statistics:

Clock Skew | 0.000
Setup Relationship | 17.800
Logic Level | 13
Arrival Clock Path Delay | cell: 1.288, 31.105%; route: 2.854, 68.895%
Arrival Data Path Delay | cell: 5.166, 37.477%; route: 8.288, 60.124%; tC2Q: 0.331, 2.399%
Required Clock Path Delay | cell: 1.288, 31.105%; route: 2.854, 68.895%

### Path5

Path Summary:

Slack | 0.574
Data Arrival Time | 17.908
Data Required Time | 18.482
From | g_sound.u_adc_farm/u_scan0/sample_channel_0_s0
To | g_sound.u_calib0/n909_s
Launch Clk | clk_sys:[R]
Latch Clk | clk_sys:[R]

Data Arrival Path:

AT | DELAY | TYPE | RF | FANOUT | LOC | NODE
0.000 | 0.000 | | | | | active clock edge time
0.000 | 0.000 | | | | | clk_sys
0.000 | 0.000 | tCL | RR | 1 | IOB117[B] | clk_ibuf/I
1.288 | 1.288 | tINS | RR | 17287 | IOB117[B] | clk_ibuf/O
4.150 | 2.862 | tNET | RR | 1 | R62C108[0][B] | g_sound.u_adc_farm/u_scan0/sample_channel_0_s0/CLK
4.495 | 0.344 | tC2Q | RR | 147 | R62C108[0][B] | g_sound.u_adc_farm/u_scan0/sample_channel_0_s0/Q
7.030 | 2.536 | tNET | RR | 1 | R64C56[0][A] | g_sound.u_calib0/n4_s16/I2
7.504 | 0.474 | tINS | RR | 1 | R64C56[0][A] | g_sound.u_calib0/n4_s16/F
7.504 | 0.000 | tNET | RR | 1 | R64C56[0][A] | g_sound.u_calib0/n4_s13/I0
7.627 | 0.123 | tINS | RR | 1 | R64C56[0][A] | g_sound.u_calib0/n4_s13/O
7.627 | 0.000 | tNET | RR | 1 | R64C56[0][B] | g_sound.u_calib0/n4_s11/I1
7.704 | 0.078 | tINS | RR | 51 | R64C56[0][B] | g_sound.u_calib0/n4_s11/O
9.299 | 1.595 | tNET | RR | 1 | R61C50[3][B] | g_sound.u_calib0/zero_rd_8_s2/I0
9.769 | 0.469 | tINS | RR | 5 | R61C50[3][B] | g_sound.u_calib0/zero_rd_8_s2/F
10.694 | 0.926 | tNET | RR | 1 | R58C56[0][B] | g_sound.u_calib0/dclamp_9_s11/I3
11.159 | 0.465 | tINS | RR | 1 | R58C56[0][B] | g_sound.u_calib0/dclamp_9_s11/F
11.283 | 0.124 | tNET | RR | 1 | R58C56[3][B] | g_sound.u_calib0/dclamp_9_s5/I1
11.731 | 0.448 | tINS | RR | 2 | R58C56[3][B] | g_sound.u_calib0/dclamp_9_s5/F
11.857 | 0.126 | tNET | RR | 1 | R58C56[3][A] | g_sound.u_calib0/dclamp_9_s3/I0
12.326 | 0.469 | tINS | RR | 18 | R58C56[3][A] | g_sound.u_calib0/dclamp_9_s3/F
14.162 | 1.836 | tNET | RR | 1 | R55C53[1][A] | g_sound.u_calib0/dclamp_8_s1/I1
14.626 | 0.465 | tINS | RR | 3 | R55C53[1][A] | g_sound.u_calib0/dclamp_8_s1/F
14.773 | 0.146 | tNET | RR | 1 | R55C54[0][B] | g_sound.u_calib0/dclamp_8_s11/I1
15.246 | 0.474 | tINS | RR | 1 | R55C54[0][B] | g_sound.u_calib0/dclamp_8_s11/F
15.370 | 0.124 | tNET | RR | 1 | R55C54[1][A] | g_sound.u_calib0/dclamp_8_s6/I3
15.606 | 0.236 | tINS | RR | 5 | R55C54[1][A] | g_sound.u_calib0/dclamp_8_s6/F
15.928 | 0.322 | tNET | RR | 1 | R52C54[1][A] | g_sound.u_calib0/dclamp_2_s2/I1
16.402 | 0.474 | tINS | RR | 3 | R52C54[1][A] | g_sound.u_calib0/dclamp_2_s2/F
16.548 | 0.146 | tNET | RR | 1 | R52C55[0][A] | g_sound.u_calib0/dclamp_0_s0/I3
16.963 | 0.415 | tINS | RR | 1 | R52C55[0][A] | g_sound.u_calib0/dclamp_0_s0/F
17.908 | 0.945 | tNET | RR | 1 | DSP_R47[14] | g_sound.u_calib0/n909_s/A[0]

Data Required Path:

AT | DELAY | TYPE | RF | FANOUT | LOC | NODE
17.800 | 17.800 | | | | | active clock edge time
17.800 | 0.000 | | | | | clk_sys
17.800 | 0.000 | tCL | RR | 1 | IOB117[B] | clk_ibuf/I
19.088 | 1.288 | tINS | RR | 17287 | IOB117[B] | clk_ibuf/O
21.942 | 2.854 | tNET | RR | 1 | DSP_R47[14] | g_sound.u_calib0/n909_s/CLK[0]
18.482 | -3.459 | tSu | | 1 | DSP_R47[14] | g_sound.u_calib0/n909_s

Path Statistics:

Clock Skew | -0.008
Setup Relationship | 17.800
Logic Level | 11
Arrival Clock Path Delay | cell: 1.288, 31.042%; route: 2.862, 68.958%
Arrival Data Path Delay | cell: 4.588, 33.347%; route: 8.826, 64.151%; tC2Q: 0.344, 2.502%
Required Clock Path Delay | cell: 1.288, 31.105%; route: 2.854, 68.895%

### Path6

Path Summary:

Slack | 0.612
Data Arrival Time | 18.076
Data Required Time | 18.688
From | g_sound.u_calib_span/cur_axis_o_3_s1
To | g_sound.u_calib1/n909_s
Launch Clk | clk_sys:[R]
Latch Clk | clk_sys:[R]

Data Arrival Path:

AT | DELAY | TYPE | RF | FANOUT | LOC | NODE
0.000 | 0.000 | | | | | active clock edge time
0.000 | 0.000 | | | | | clk_sys
0.000 | 0.000 | tCL | RR | 1 | IOB117[B] | clk_ibuf/I
1.288 | 1.288 | tINS | RR | 17287 | IOB117[B] | clk_ibuf/O
4.142 | 2.854 | tNET | RR | 1 | R58C113[0][B] | g_sound.u_calib_span/cur_axis_o_3_s1/CLK
4.473 | 0.331 | tC2Q | RF | 74 | R58C113[0][B] | g_sound.u_calib_span/cur_axis_o_3_s1/Q
6.570 | 2.097 | tNET | FF | 1 | R58C104[0][A] | n4583_s1/I2
7.034 | 0.465 | tINS | FR | 13 | R58C104[0][A] | n4583_s1/F
10.921 | 3.887 | tNET | RR | 1 | R70C43[3][A] | g_sound.u_calib1/dclamp_7_s26/I2
11.182 | 0.261 | tINS | RF | 1 | R70C43[3][A] | g_sound.u_calib1/dclamp_7_s26/F
11.310 | 0.128 | tNET | FF | 1 | R69C43[3][A] | g_sound.u_calib1/dclamp_7_s18/I3
11.684 | 0.373 | tINS | FR | 1 | R69C43[3][A] | g_sound.u_calib1/dclamp_7_s18/F
11.826 | 0.142 | tNET | RR | 1 | R68C43[2][B] | g_sound.u_calib1/dclamp_7_s16/I3
12.299 | 0.474 | tINS | RR | 1 | R68C43[2][B] | g_sound.u_calib1/dclamp_7_s16/F
12.302 | 0.002 | tNET | RR | 1 | R68C43[3][B] | g_sound.u_calib1/dclamp_7_s21/I0
12.749 | 0.448 | tINS | RR | 1 | R68C43[3][B] | g_sound.u_calib1/dclamp_7_s21/F
12.891 | 0.142 | tNET | RR | 1 | R68C44[1][B] | g_sound.u_calib1/dclamp_7_s10/I1
13.306 | 0.415 | tINS | RR | 2 | R68C44[1][B] | g_sound.u_calib1/dclamp_7_s10/F
13.311 | 0.005 | tNET | RR | 1 | R68C44[1][A] | g_sound.u_calib1/dclamp_7_s6/I0
13.775 | 0.465 | tINS | RR | 2 | R68C44[1][A] | g_sound.u_calib1/dclamp_7_s6/F
14.212 | 0.436 | tNET | RR | 1 | R70C43[2][B] | g_sound.u_calib1/dclamp_7_s4/I1
14.676 | 0.465 | tINS | RR | 3 | R70C43[2][B] | g_sound.u_calib1/dclamp_7_s4/F
14.823 | 0.146 | tNET | RR | 1 | R70C42[2][B] | g_sound.u_calib1/dclamp_8_s9/I3
15.296 | 0.474 | tINS | RR | 1 | R70C42[2][B] | g_sound.u_calib1/dclamp_8_s9/F
15.438 | 0.142 | tNET | RR | 1 | R70C43[0][A] | g_sound.u_calib1/dclamp_8_s7/I1
15.853 | 0.415 | tINS | RR | 2 | R70C43[0][A] | g_sound.u_calib1/dclamp_8_s7/F
15.997 | 0.144 | tNET | RR | 1 | R70C44[2][B] | g_sound.u_calib1/dclamp_8_s4/I1
16.462 | 0.465 | tINS | RR | 9 | R70C44[2][B] | g_sound.u_calib1/dclamp_8_s4/F
16.910 | 0.448 | tNET | RR | 1 | R71C43[0][B] | g_sound.u_calib1/dclamp_3_s0/I3
17.383 | 0.474 | tINS | RR | 1 | R71C43[0][B] | g_sound.u_calib1/dclamp_3_s0/F
18.076 | 0.693 | tNET | RR | 1 | DSP_R65[13] | g_sound.u_calib1/n909_s/A[3]

Data Required Path:

AT | DELAY | TYPE | RF | FANOUT | LOC | NODE
17.800 | 17.800 | | | | | active clock edge time
17.800 | 0.000 | | | | | clk_sys
17.800 | 0.000 | tCL | RR | 1 | IOB117[B] | clk_ibuf/I
19.088 | 1.288 | tINS | RR | 17287 | IOB117[B] | clk_ibuf/O
21.942 | 2.854 | tNET | RR | 1 | DSP_R65[13] | g_sound.u_calib1/n909_s/CLK[0]
18.688 | -3.254 | tSu | | 1 | DSP_R65[13] | g_sound.u_calib1/n909_s

Path Statistics:

Clock Skew | 0.000
Setup Relationship | 17.800
Logic Level | 13
Arrival Clock Path Delay | cell: 1.288, 31.105%; route: 2.854, 68.895%
Arrival Data Path Delay | cell: 5.192, 37.260%; route: 8.412, 60.367%; tC2Q: 0.331, 2.374%
Required Clock Path Delay | cell: 1.288, 31.105%; route: 2.854, 68.895%

### Path7

Path Summary:

Slack | 0.613
Data Arrival Time | 18.075
Data Required Time | 18.688
From | g_sound.u_calib_span/cur_axis_o_3_s1
To | g_sound.u_calib1/n909_s
Launch Clk | clk_sys:[R]
Latch Clk | clk_sys:[R]

Data Arrival Path:

AT | DELAY | TYPE | RF | FANOUT | LOC | NODE
0.000 | 0.000 | | | | | active clock edge time
0.000 | 0.000 | | | | | clk_sys
0.000 | 0.000 | tCL | RR | 1 | IOB117[B] | clk_ibuf/I
1.288 | 1.288 | tINS | RR | 17287 | IOB117[B] | clk_ibuf/O
4.142 | 2.854 | tNET | RR | 1 | R58C113[0][B] | g_sound.u_calib_span/cur_axis_o_3_s1/CLK
4.473 | 0.331 | tC2Q | RF | 74 | R58C113[0][B] | g_sound.u_calib_span/cur_axis_o_3_s1/Q
6.570 | 2.097 | tNET | FF | 1 | R58C104[0][A] | n4583_s1/I2
7.034 | 0.465 | tINS | FR | 13 | R58C104[0][A] | n4583_s1/F
10.921 | 3.887 | tNET | RR | 1 | R70C43[3][A] | g_sound.u_calib1/dclamp_7_s26/I2
11.182 | 0.261 | tINS | RF | 1 | R70C43[3][A] | g_sound.u_calib1/dclamp_7_s26/F
11.310 | 0.128 | tNET | FF | 1 | R69C43[3][A] | g_sound.u_calib1/dclamp_7_s18/I3
11.684 | 0.373 | tINS | FR | 1 | R69C43[3][A] | g_sound.u_calib1/dclamp_7_s18/F
11.826 | 0.142 | tNET | RR | 1 | R68C43[2][B] | g_sound.u_calib1/dclamp_7_s16/I3
12.299 | 0.474 | tINS | RR | 1 | R68C43[2][B] | g_sound.u_calib1/dclamp_7_s16/F
12.302 | 0.002 | tNET | RR | 1 | R68C43[3][B] | g_sound.u_calib1/dclamp_7_s21/I0
12.749 | 0.448 | tINS | RR | 1 | R68C43[3][B] | g_sound.u_calib1/dclamp_7_s21/F
12.891 | 0.142 | tNET | RR | 1 | R68C44[1][B] | g_sound.u_calib1/dclamp_7_s10/I1
13.306 | 0.415 | tINS | RR | 2 | R68C44[1][B] | g_sound.u_calib1/dclamp_7_s10/F
13.311 | 0.005 | tNET | RR | 1 | R68C44[1][A] | g_sound.u_calib1/dclamp_7_s6/I0
13.775 | 0.465 | tINS | RR | 2 | R68C44[1][A] | g_sound.u_calib1/dclamp_7_s6/F
14.212 | 0.436 | tNET | RR | 1 | R70C43[2][B] | g_sound.u_calib1/dclamp_7_s4/I1
14.676 | 0.465 | tINS | RR | 3 | R70C43[2][B] | g_sound.u_calib1/dclamp_7_s4/F
14.823 | 0.146 | tNET | RR | 1 | R70C42[2][B] | g_sound.u_calib1/dclamp_8_s9/I3
15.296 | 0.474 | tINS | RR | 1 | R70C42[2][B] | g_sound.u_calib1/dclamp_8_s9/F
15.438 | 0.142 | tNET | RR | 1 | R70C43[0][A] | g_sound.u_calib1/dclamp_8_s7/I1
15.853 | 0.415 | tINS | RR | 2 | R70C43[0][A] | g_sound.u_calib1/dclamp_8_s7/F
15.997 | 0.144 | tNET | RR | 1 | R70C44[2][B] | g_sound.u_calib1/dclamp_8_s4/I1
16.462 | 0.465 | tINS | RR | 9 | R70C44[2][B] | g_sound.u_calib1/dclamp_8_s4/F
16.910 | 0.448 | tNET | RR | 1 | R71C43[1][A] | g_sound.u_calib1/dclamp_6_s0/I3
17.325 | 0.415 | tINS | RR | 1 | R71C43[1][A] | g_sound.u_calib1/dclamp_6_s0/F
18.075 | 0.750 | tNET | RR | 1 | DSP_R65[13] | g_sound.u_calib1/n909_s/A[6]

Data Required Path:

AT | DELAY | TYPE | RF | FANOUT | LOC | NODE
17.800 | 17.800 | | | | | active clock edge time
17.800 | 0.000 | | | | | clk_sys
17.800 | 0.000 | tCL | RR | 1 | IOB117[B] | clk_ibuf/I
19.088 | 1.288 | tINS | RR | 17287 | IOB117[B] | clk_ibuf/O
21.942 | 2.854 | tNET | RR | 1 | DSP_R65[13] | g_sound.u_calib1/n909_s/CLK[0]
18.688 | -3.254 | tSu | | 1 | DSP_R65[13] | g_sound.u_calib1/n909_s

Path Statistics:

Clock Skew | 0.000
Setup Relationship | 17.800
Logic Level | 13
Arrival Clock Path Delay | cell: 1.288, 31.105%; route: 2.854, 68.895%
Arrival Data Path Delay | cell: 5.133, 36.843%; route: 8.469, 60.783%; tC2Q: 0.331, 2.374%
Required Clock Path Delay | cell: 1.288, 31.105%; route: 2.854, 68.895%

### Path8

Path Summary:

Slack | 0.645
Data Arrival Time | 17.896
Data Required Time | 18.541
From | g_sound.u_calib_span/cur_axis_o_3_s1
To | g_sound.u_calib1/n909_s
Launch Clk | clk_sys:[R]
Latch Clk | clk_sys:[R]

Data Arrival Path:

AT | DELAY | TYPE | RF | FANOUT | LOC | NODE
0.000 | 0.000 | | | | | active clock edge time
0.000 | 0.000 | | | | | clk_sys
0.000 | 0.000 | tCL | RR | 1 | IOB117[B] | clk_ibuf/I
1.288 | 1.288 | tINS | RR | 17287 | IOB117[B] | clk_ibuf/O
4.142 | 2.854 | tNET | RR | 1 | R58C113[0][B] | g_sound.u_calib_span/cur_axis_o_3_s1/CLK
4.473 | 0.331 | tC2Q | RF | 74 | R58C113[0][B] | g_sound.u_calib_span/cur_axis_o_3_s1/Q
6.570 | 2.097 | tNET | FF | 1 | R58C104[0][A] | n4583_s1/I2
7.034 | 0.465 | tINS | FR | 13 | R58C104[0][A] | n4583_s1/F
10.921 | 3.887 | tNET | RR | 1 | R70C43[3][A] | g_sound.u_calib1/dclamp_7_s26/I2
11.182 | 0.261 | tINS | RF | 1 | R70C43[3][A] | g_sound.u_calib1/dclamp_7_s26/F
11.310 | 0.128 | tNET | FF | 1 | R69C43[3][A] | g_sound.u_calib1/dclamp_7_s18/I3
11.684 | 0.373 | tINS | FR | 1 | R69C43[3][A] | g_sound.u_calib1/dclamp_7_s18/F
11.826 | 0.142 | tNET | RR | 1 | R68C43[2][B] | g_sound.u_calib1/dclamp_7_s16/I3
12.299 | 0.474 | tINS | RR | 1 | R68C43[2][B] | g_sound.u_calib1/dclamp_7_s16/F
12.302 | 0.002 | tNET | RR | 1 | R68C43[3][B] | g_sound.u_calib1/dclamp_7_s21/I0
12.749 | 0.448 | tINS | RR | 1 | R68C43[3][B] | g_sound.u_calib1/dclamp_7_s21/F
12.891 | 0.142 | tNET | RR | 1 | R68C44[1][B] | g_sound.u_calib1/dclamp_7_s10/I1
13.306 | 0.415 | tINS | RR | 2 | R68C44[1][B] | g_sound.u_calib1/dclamp_7_s10/F
13.311 | 0.005 | tNET | RR | 1 | R68C44[1][A] | g_sound.u_calib1/dclamp_7_s6/I0
13.775 | 0.465 | tINS | RR | 2 | R68C44[1][A] | g_sound.u_calib1/dclamp_7_s6/F
14.212 | 0.436 | tNET | RR | 1 | R70C43[2][B] | g_sound.u_calib1/dclamp_7_s4/I1
14.676 | 0.465 | tINS | RR | 3 | R70C43[2][B] | g_sound.u_calib1/dclamp_7_s4/F
14.823 | 0.146 | tNET | RR | 1 | R70C42[2][B] | g_sound.u_calib1/dclamp_8_s9/I3
15.296 | 0.474 | tINS | RR | 1 | R70C42[2][B] | g_sound.u_calib1/dclamp_8_s9/F
15.438 | 0.142 | tNET | RR | 1 | R70C43[0][A] | g_sound.u_calib1/dclamp_8_s7/I1
15.853 | 0.415 | tINS | RR | 2 | R70C43[0][A] | g_sound.u_calib1/dclamp_8_s7/F
15.997 | 0.144 | tNET | RR | 1 | R70C44[2][B] | g_sound.u_calib1/dclamp_8_s4/I1
16.462 | 0.465 | tINS | RR | 9 | R70C44[2][B] | g_sound.u_calib1/dclamp_8_s4/F
16.910 | 0.448 | tNET | RR | 1 | R71C43[2][B] | g_sound.u_calib1/dclamp_2_s0/I3
17.325 | 0.415 | tINS | RR | 1 | R71C43[2][B] | g_sound.u_calib1/dclamp_2_s0/F
17.896 | 0.572 | tNET | RR | 1 | DSP_R65[13] | g_sound.u_calib1/n909_s/A[2]

Data Required Path:

AT | DELAY | TYPE | RF | FANOUT | LOC | NODE
17.800 | 17.800 | | | | | active clock edge time
17.800 | 0.000 | | | | | clk_sys
17.800 | 0.000 | tCL | RR | 1 | IOB117[B] | clk_ibuf/I
19.088 | 1.288 | tINS | RR | 17287 | IOB117[B] | clk_ibuf/O
21.942 | 2.854 | tNET | RR | 1 | DSP_R65[13] | g_sound.u_calib1/n909_s/CLK[0]
18.541 | -3.401 | tSu | | 1 | DSP_R65[13] | g_sound.u_calib1/n909_s

Path Statistics:

Clock Skew | 0.000
Setup Relationship | 17.800
Logic Level | 13
Arrival Clock Path Delay | cell: 1.288, 31.105%; route: 2.854, 68.895%
Arrival Data Path Delay | cell: 5.133, 37.322%; route: 8.290, 60.273%; tC2Q: 0.331, 2.405%
Required Clock Path Delay | cell: 1.288, 31.105%; route: 2.854, 68.895%

### Path9

Path Summary:

Slack | 0.657
Data Arrival Time | 18.035
Data Required Time | 18.692
From | g_sound.u_adc_farm/u_scan0/sample_channel_0_s0
To | g_sound.u_calib0/n909_s
Launch Clk | clk_sys:[R]
Latch Clk | clk_sys:[R]

Data Arrival Path:

AT | DELAY | TYPE | RF | FANOUT | LOC | NODE
0.000 | 0.000 | | | | | active clock edge time
0.000 | 0.000 | | | | | clk_sys
0.000 | 0.000 | tCL | RR | 1 | IOB117[B] | clk_ibuf/I
1.288 | 1.288 | tINS | RR | 17287 | IOB117[B] | clk_ibuf/O
4.150 | 2.862 | tNET | RR | 1 | R62C108[0][B] | g_sound.u_adc_farm/u_scan0/sample_channel_0_s0/CLK
4.495 | 0.344 | tC2Q | RR | 147 | R62C108[0][B] | g_sound.u_adc_farm/u_scan0/sample_channel_0_s0/Q
7.030 | 2.536 | tNET | RR | 1 | R64C56[0][A] | g_sound.u_calib0/n4_s16/I2
7.504 | 0.474 | tINS | RR | 1 | R64C56[0][A] | g_sound.u_calib0/n4_s16/F
7.504 | 0.000 | tNET | RR | 1 | R64C56[0][A] | g_sound.u_calib0/n4_s13/I0
7.627 | 0.123 | tINS | RR | 1 | R64C56[0][A] | g_sound.u_calib0/n4_s13/O
7.627 | 0.000 | tNET | RR | 1 | R64C56[0][B] | g_sound.u_calib0/n4_s11/I1
7.704 | 0.078 | tINS | RR | 51 | R64C56[0][B] | g_sound.u_calib0/n4_s11/O
9.299 | 1.595 | tNET | RR | 1 | R61C50[3][B] | g_sound.u_calib0/zero_rd_8_s2/I0
9.769 | 0.469 | tINS | RR | 5 | R61C50[3][B] | g_sound.u_calib0/zero_rd_8_s2/F
10.694 | 0.926 | tNET | RR | 1 | R58C56[0][B] | g_sound.u_calib0/dclamp_9_s11/I3
11.159 | 0.465 | tINS | RR | 1 | R58C56[0][B] | g_sound.u_calib0/dclamp_9_s11/F
11.283 | 0.124 | tNET | RR | 1 | R58C56[3][B] | g_sound.u_calib0/dclamp_9_s5/I1
11.731 | 0.448 | tINS | RR | 2 | R58C56[3][B] | g_sound.u_calib0/dclamp_9_s5/F
11.857 | 0.126 | tNET | RR | 1 | R58C56[3][A] | g_sound.u_calib0/dclamp_9_s3/I0
12.326 | 0.469 | tINS | RR | 18 | R58C56[3][A] | g_sound.u_calib0/dclamp_9_s3/F
14.162 | 1.836 | tNET | RR | 1 | R55C53[1][A] | g_sound.u_calib0/dclamp_8_s1/I1
14.626 | 0.465 | tINS | RR | 3 | R55C53[1][A] | g_sound.u_calib0/dclamp_8_s1/F
14.773 | 0.146 | tNET | RR | 1 | R55C54[0][A] | g_sound.u_calib0/dclamp_8_s13/I1
15.246 | 0.474 | tINS | RR | 2 | R55C54[0][A] | g_sound.u_calib0/dclamp_8_s13/F
15.390 | 0.144 | tNET | RR | 1 | R54C54[0][A] | g_sound.u_calib0/dclamp_8_s7/I1
15.864 | 0.474 | tINS | RR | 4 | R54C54[0][A] | g_sound.u_calib0/dclamp_8_s7/F
16.165 | 0.301 | tNET | RR | 1 | R52C54[2][B] | g_sound.u_calib0/dclamp_5_s3/I3
16.630 | 0.465 | tINS | RR | 1 | R52C54[2][B] | g_sound.u_calib0/dclamp_5_s3/F
16.772 | 0.142 | tNET | RR | 1 | R52C53[2][A] | g_sound.u_calib0/dclamp_5_s0/I3
17.187 | 0.415 | tINS | RR | 1 | R52C53[2][A] | g_sound.u_calib0/dclamp_5_s0/F
18.035 | 0.848 | tNET | RR | 1 | DSP_R47[14] | g_sound.u_calib0/n909_s/A[5]

Data Required Path:

AT | DELAY | TYPE | RF | FANOUT | LOC | NODE
17.800 | 17.800 | | | | | active clock edge time
17.800 | 0.000 | | | | | clk_sys
17.800 | 0.000 | tCL | RR | 1 | IOB117[B] | clk_ibuf/I
19.088 | 1.288 | tINS | RR | 17287 | IOB117[B] | clk_ibuf/O
21.942 | 2.854 | tNET | RR | 1 | DSP_R47[14] | g_sound.u_calib0/n909_s/CLK[0]
18.692 | -3.250 | tSu | | 1 | DSP_R47[14] | g_sound.u_calib0/n909_s

Path Statistics:

Clock Skew | -0.008
Setup Relationship | 17.800
Logic Level | 11
Arrival Clock Path Delay | cell: 1.288, 31.042%; route: 2.862, 68.958%
Arrival Data Path Delay | cell: 4.816, 34.686%; route: 8.724, 62.834%; tC2Q: 0.344, 2.479%
Required Clock Path Delay | cell: 1.288, 31.105%; route: 2.854, 68.895%

### Path10

Path Summary:

Slack | 0.657
Data Arrival Time | 21.219
Data Required Time | 21.876
From | g_sound.u_fader_gear/gear_o_0_s0
To | g_sound.u_vibrato_lfo/rate_inc_q_26_s0
Launch Clk | clk_sys:[R]
Latch Clk | clk_sys:[R]

Data Arrival Path:

AT | DELAY | TYPE | RF | FANOUT | LOC | NODE
0.000 | 0.000 | | | | | active clock edge time
0.000 | 0.000 | | | | | clk_sys
0.000 | 0.000 | tCL | RR | 1 | IOB117[B] | clk_ibuf/I
1.288 | 1.288 | tINS | RR | 17287 | IOB117[B] | clk_ibuf/O
4.142 | 2.854 | tNET | RR | 1 | R60C109[0][A] | g_sound.u_fader_gear/gear_o_0_s0/CLK
4.486 | 0.344 | tC2Q | RR | 23 | R60C109[0][A] | g_sound.u_fader_gear/gear_o_0_s0/Q
6.011 | 1.524 | tNET | RR | 1 | R66C119[3][B] | g_sound.u_fader_gear/g_sound.vib_rate_sel_0_s/I0
6.458 | 0.448 | tINS | RR | 1 | R66C119[3][B] | g_sound.u_fader_gear/g_sound.vib_rate_sel_0_s/F
7.519 | 1.061 | tNET | RR | 97 | DSP_R65[31] | g_sound.u_vibrato_lfo/rate_product_0_s/A[0]
10.176 | 2.657 | tINS | RR | 3 | DSP_R65[31] | g_sound.u_vibrato_lfo/rate_product_0_s/DOUT[15]
11.142 | 0.966 | tNET | RR | 1 | R68C116[0][A] | g_sound.u_vibrato_lfo/rate_target_w_5_s3/I2
11.607 | 0.465 | tINS | RR | 3 | R68C116[0][A] | g_sound.u_vibrato_lfo/rate_target_w_5_s3/F
11.753 | 0.146 | tNET | RR | 1 | R69C116[2][B] | g_sound.u_vibrato_lfo/rate_target_w_8_s3/I0
12.218 | 0.465 | tINS | RR | 4 | R69C116[2][B] | g_sound.u_vibrato_lfo/rate_target_w_8_s3/F
12.537 | 0.319 | tNET | RR | 1 | R68C117[2][A] | g_sound.u_vibrato_lfo/rate_target_w_9_s2/I1
13.002 | 0.465 | tINS | RR | 8 | R68C117[2][A] | g_sound.u_vibrato_lfo/rate_target_w_9_s2/F
13.614 | 0.612 | tNET | RR | 2 | R71C116[1][B] | g_sound.u_vibrato_lfo/n462_s/I0
14.114 | 0.501 | tINS | RF | 1 | R71C116[1][B] | g_sound.u_vibrato_lfo/n462_s/COUT
14.114 | 0.000 | tNET | FF | 2 | R71C116[2][A] | g_sound.u_vibrato_lfo/n461_s/CIN
14.159 | 0.045 | tINS | FR | 1 | R71C116[2][A] | g_sound.u_vibrato_lfo/n461_s/COUT
14.159 | 0.000 | tNET | RR | 2 | R71C116[2][B] | g_sound.u_vibrato_lfo/n460_s/CIN
14.204 | 0.045 | tINS | RR | 1 | R71C116[2][B] | g_sound.u_vibrato_lfo/n460_s/COUT
14.204 | 0.000 | tNET | RR | 2 | R71C117[0][A] | g_sound.u_vibrato_lfo/n459_s/CIN
14.249 | 0.045 | tINS | RR | 1 | R71C117[0][A] | g_sound.u_vibrato_lfo/n459_s/COUT
14.249 | 0.000 | tNET | RR | 2 | R71C117[0][B] | g_sound.u_vibrato_lfo/n458_s/CIN
14.294 | 0.045 | tINS | RR | 1 | R71C117[0][B] | g_sound.u_vibrato_lfo/n458_s/COUT
14.294 | 0.000 | tNET | RR | 2 | R71C117[1][A] | g_sound.u_vibrato_lfo/n457_s/CIN
14.339 | 0.045 | tINS | RR | 1 | R71C117[1][A] | g_sound.u_vibrato_lfo/n457_s/COUT
14.339 | 0.000 | tNET | RR | 2 | R71C117[1][B] | g_sound.u_vibrato_lfo/n456_s/CIN
14.384 | 0.045 | tINS | RR | 1 | R71C117[1][B] | g_sound.u_vibrato_lfo/n456_s/COUT
14.384 | 0.000 | tNET | RR | 2 | R71C117[2][A] | g_sound.u_vibrato_lfo/n455_s/CIN
14.429 | 0.045 | tINS | RR | 1 | R71C117[2][A] | g_sound.u_vibrato_lfo/n455_s/COUT
14.429 | 0.000 | tNET | RR | 2 | R71C117[2][B] | g_sound.u_vibrato_lfo/n454_s/CIN
14.474 | 0.045 | tINS | RR | 1 | R71C117[2][B] | g_sound.u_vibrato_lfo/n454_s/COUT
14.474 | 0.000 | tNET | RR | 2 | R71C118[0][A] | g_sound.u_vibrato_lfo/n453_s/CIN
14.519 | 0.045 | tINS | RR | 1 | R71C118[0][A] | g_sound.u_vibrato_lfo/n453_s/COUT
14.519 | 0.000 | tNET | RR | 2 | R71C118[0][B] | g_sound.u_vibrato_lfo/n452_s/CIN
14.564 | 0.045 | tINS | RR | 1 | R71C118[0][B] | g_sound.u_vibrato_lfo/n452_s/COUT
14.564 | 0.000 | tNET | RR | 2 | R71C118[1][A] | g_sound.u_vibrato_lfo/n451_s/CIN
14.609 | 0.045 | tINS | RR | 1 | R71C118[1][A] | g_sound.u_vibrato_lfo/n451_s/COUT
14.609 | 0.000 | tNET | RR | 2 | R71C118[1][B] | g_sound.u_vibrato_lfo/n450_s/CIN
14.654 | 0.045 | tINS | RR | 1 | R71C118[1][B] | g_sound.u_vibrato_lfo/n450_s/COUT
14.654 | 0.000 | tNET | RR | 2 | R71C118[2][A] | g_sound.u_vibrato_lfo/n449_s/CIN
14.699 | 0.045 | tINS | RR | 1 | R71C118[2][A] | g_sound.u_vibrato_lfo/n449_s/COUT
14.699 | 0.000 | tNET | RR | 2 | R71C118[2][B] | g_sound.u_vibrato_lfo/n448_s/CIN
14.970 | 0.271 | tINS | RF | 1 | R71C118[2][B] | g_sound.u_vibrato_lfo/n448_s/SUM
14.975 | 0.005 | tNET | FF | 1 | R71C118[3][A] | g_sound.u_vibrato_lfo/n651_s19/I1
15.423 | 0.448 | tINS | FR | 1 | R71C118[3][A] | g_sound.u_vibrato_lfo/n651_s19/F
15.425 | 0.002 | tNET | RR | 1 | R71C118[3][B] | g_sound.u_vibrato_lfo/n651_s18/I3
15.798 | 0.373 | tINS | RR | 1 | R71C118[3][B] | g_sound.u_vibrato_lfo/n651_s18/F
16.111 | 0.313 | tNET | RR | 1 | R72C116[0][B] | g_sound.u_vibrato_lfo/n651_s15/I3
16.526 | 0.415 | tINS | RR | 1 | R72C116[0][B] | g_sound.u_vibrato_lfo/n651_s15/F
16.821 | 0.295 | tNET | RR | 1 | R71C116[3][A] | g_sound.u_vibrato_lfo/n651_s11/I3
17.290 | 0.469 | tINS | RR | 1 | R71C116[3][A] | g_sound.u_vibrato_lfo/n651_s11/F
17.657 | 0.367 | tNET | RR | 1 | R71C119[3][B] | g_sound.u_vibrato_lfo/n651_s7/I3
18.105 | 0.448 | tINS | RR | 4 | R71C119[3][B] | g_sound.u_vibrato_lfo/n651_s7/F
18.820 | 0.715 | tNET | RR | 1 | R72C115[1][B] | g_sound.u_vibrato_lfo/n651_s2/I0
19.294 | 0.474 | tINS | RR | 19 | R72C115[1][B] | g_sound.u_vibrato_lfo/n651_s2/F
20.804 | 1.510 | tNET | RR | 1 | R72C122[1][A] | g_sound.u_vibrato_lfo/n667_s0/I2
21.219 | 0.415 | tINS | RR | 1 | R72C122[1][A] | g_sound.u_vibrato_lfo/n667_s0/F
21.219 | 0.000 | tNET | RR | 1 | R72C122[1][A] | g_sound.u_vibrato_lfo/rate_inc_q_26_s0/D

Data Required Path:

AT | DELAY | TYPE | RF | FANOUT | LOC | NODE
17.800 | 17.800 | | | | | active clock edge time
17.800 | 0.000 | | | | | clk_sys
17.800 | 0.000 | tCL | RR | 1 | IOB117[B] | clk_ibuf/I
19.088 | 1.288 | tINS | RR | 17287 | IOB117[B] | clk_ibuf/O
21.933 | 2.845 | tNET | RR | 1 | R72C122[1][A] | g_sound.u_vibrato_lfo/rate_inc_q_26_s0/CLK
21.876 | -0.057 | tSu | | 1 | R72C122[1][A] | g_sound.u_vibrato_lfo/rate_inc_q_26_s0

Path Statistics:

Clock Skew | -0.008
Setup Relationship | 17.800
Logic Level | 16
Arrival Clock Path Delay | cell: 1.288, 31.105%; route: 2.854, 68.895%
Arrival Data Path Delay | cell: 8.897, 52.099%; route: 7.836, 45.885%; tC2Q: 0.344, 2.016%
Required Clock Path Delay | cell: 1.288, 31.169%; route: 2.845, 68.831%

### Path11

Path Summary:

Slack | 0.666
Data Arrival Time | 17.896
Data Required Time | 18.562
From | g_sound.u_calib_span/cur_axis_o_3_s1
To | g_sound.u_calib1/n909_s
Launch Clk | clk_sys:[R]
Latch Clk | clk_sys:[R]

Data Arrival Path:

AT | DELAY | TYPE | RF | FANOUT | LOC | NODE
0.000 | 0.000 | | | | | active clock edge time
0.000 | 0.000 | | | | | clk_sys
0.000 | 0.000 | tCL | RR | 1 | IOB117[B] | clk_ibuf/I
1.288 | 1.288 | tINS | RR | 17287 | IOB117[B] | clk_ibuf/O
4.142 | 2.854 | tNET | RR | 1 | R58C113[0][B] | g_sound.u_calib_span/cur_axis_o_3_s1/CLK
4.473 | 0.331 | tC2Q | RF | 74 | R58C113[0][B] | g_sound.u_calib_span/cur_axis_o_3_s1/Q
6.570 | 2.097 | tNET | FF | 1 | R58C104[0][A] | n4583_s1/I2
7.034 | 0.465 | tINS | FR | 13 | R58C104[0][A] | n4583_s1/F
10.921 | 3.887 | tNET | RR | 1 | R70C43[3][A] | g_sound.u_calib1/dclamp_7_s26/I2
11.182 | 0.261 | tINS | RF | 1 | R70C43[3][A] | g_sound.u_calib1/dclamp_7_s26/F
11.310 | 0.128 | tNET | FF | 1 | R69C43[3][A] | g_sound.u_calib1/dclamp_7_s18/I3
11.684 | 0.373 | tINS | FR | 1 | R69C43[3][A] | g_sound.u_calib1/dclamp_7_s18/F
11.826 | 0.142 | tNET | RR | 1 | R68C43[2][B] | g_sound.u_calib1/dclamp_7_s16/I3
12.299 | 0.474 | tINS | RR | 1 | R68C43[2][B] | g_sound.u_calib1/dclamp_7_s16/F
12.302 | 0.002 | tNET | RR | 1 | R68C43[3][B] | g_sound.u_calib1/dclamp_7_s21/I0
12.749 | 0.448 | tINS | RR | 1 | R68C43[3][B] | g_sound.u_calib1/dclamp_7_s21/F
12.891 | 0.142 | tNET | RR | 1 | R68C44[1][B] | g_sound.u_calib1/dclamp_7_s10/I1
13.306 | 0.415 | tINS | RR | 2 | R68C44[1][B] | g_sound.u_calib1/dclamp_7_s10/F
13.311 | 0.005 | tNET | RR | 1 | R68C44[1][A] | g_sound.u_calib1/dclamp_7_s6/I0
13.775 | 0.465 | tINS | RR | 2 | R68C44[1][A] | g_sound.u_calib1/dclamp_7_s6/F
14.212 | 0.436 | tNET | RR | 1 | R70C43[2][B] | g_sound.u_calib1/dclamp_7_s4/I1
14.676 | 0.465 | tINS | RR | 3 | R70C43[2][B] | g_sound.u_calib1/dclamp_7_s4/F
14.823 | 0.146 | tNET | RR | 1 | R70C42[2][B] | g_sound.u_calib1/dclamp_8_s9/I3
15.296 | 0.474 | tINS | RR | 1 | R70C42[2][B] | g_sound.u_calib1/dclamp_8_s9/F
15.438 | 0.142 | tNET | RR | 1 | R70C43[0][A] | g_sound.u_calib1/dclamp_8_s7/I1
15.853 | 0.415 | tINS | RR | 2 | R70C43[0][A] | g_sound.u_calib1/dclamp_8_s7/F
15.997 | 0.144 | tNET | RR | 1 | R70C44[2][B] | g_sound.u_calib1/dclamp_8_s4/I1
16.462 | 0.465 | tINS | RR | 9 | R70C44[2][B] | g_sound.u_calib1/dclamp_8_s4/F
16.910 | 0.448 | tNET | RR | 1 | R71C43[2][A] | g_sound.u_calib1/dclamp_1_s0/I3
17.325 | 0.415 | tINS | RR | 1 | R71C43[2][A] | g_sound.u_calib1/dclamp_1_s0/F
17.896 | 0.572 | tNET | RR | 1 | DSP_R65[13] | g_sound.u_calib1/n909_s/A[1]

Data Required Path:

AT | DELAY | TYPE | RF | FANOUT | LOC | NODE
17.800 | 17.800 | | | | | active clock edge time
17.800 | 0.000 | | | | | clk_sys
17.800 | 0.000 | tCL | RR | 1 | IOB117[B] | clk_ibuf/I
19.088 | 1.288 | tINS | RR | 17287 | IOB117[B] | clk_ibuf/O
21.942 | 2.854 | tNET | RR | 1 | DSP_R65[13] | g_sound.u_calib1/n909_s/CLK[0]
18.562 | -3.379 | tSu | | 1 | DSP_R65[13] | g_sound.u_calib1/n909_s

Path Statistics:

Clock Skew | 0.000
Setup Relationship | 17.800
Logic Level | 13
Arrival Clock Path Delay | cell: 1.288, 31.105%; route: 2.854, 68.895%
Arrival Data Path Delay | cell: 5.133, 37.322%; route: 8.290, 60.273%; tC2Q: 0.331, 2.405%
Required Clock Path Delay | cell: 1.288, 31.105%; route: 2.854, 68.895%

### Path12

Path Summary:

Slack | 0.696
Data Arrival Time | 17.866
Data Required Time | 18.562
From | g_sound.u_adc_farm/u_scan0/sample_channel_0_s0
To | g_sound.u_calib0/n909_s
Launch Clk | clk_sys:[R]
Latch Clk | clk_sys:[R]

Data Arrival Path:

AT | DELAY | TYPE | RF | FANOUT | LOC | NODE
0.000 | 0.000 | | | | | active clock edge time
0.000 | 0.000 | | | | | clk_sys
0.000 | 0.000 | tCL | RR | 1 | IOB117[B] | clk_ibuf/I
1.288 | 1.288 | tINS | RR | 17287 | IOB117[B] | clk_ibuf/O
4.150 | 2.862 | tNET | RR | 1 | R62C108[0][B] | g_sound.u_adc_farm/u_scan0/sample_channel_0_s0/CLK
4.495 | 0.344 | tC2Q | RR | 147 | R62C108[0][B] | g_sound.u_adc_farm/u_scan0/sample_channel_0_s0/Q
7.030 | 2.536 | tNET | RR | 1 | R64C56[0][A] | g_sound.u_calib0/n4_s16/I2
7.504 | 0.474 | tINS | RR | 1 | R64C56[0][A] | g_sound.u_calib0/n4_s16/F
7.504 | 0.000 | tNET | RR | 1 | R64C56[0][A] | g_sound.u_calib0/n4_s13/I0
7.627 | 0.123 | tINS | RR | 1 | R64C56[0][A] | g_sound.u_calib0/n4_s13/O
7.627 | 0.000 | tNET | RR | 1 | R64C56[0][B] | g_sound.u_calib0/n4_s11/I1
7.704 | 0.078 | tINS | RR | 51 | R64C56[0][B] | g_sound.u_calib0/n4_s11/O
9.299 | 1.595 | tNET | RR | 1 | R61C50[3][B] | g_sound.u_calib0/zero_rd_8_s2/I0
9.769 | 0.469 | tINS | RR | 5 | R61C50[3][B] | g_sound.u_calib0/zero_rd_8_s2/F
10.694 | 0.926 | tNET | RR | 1 | R58C56[0][B] | g_sound.u_calib0/dclamp_9_s11/I3
11.159 | 0.465 | tINS | RR | 1 | R58C56[0][B] | g_sound.u_calib0/dclamp_9_s11/F
11.283 | 0.124 | tNET | RR | 1 | R58C56[3][B] | g_sound.u_calib0/dclamp_9_s5/I1
11.731 | 0.448 | tINS | RR | 2 | R58C56[3][B] | g_sound.u_calib0/dclamp_9_s5/F
11.857 | 0.126 | tNET | RR | 1 | R58C56[3][A] | g_sound.u_calib0/dclamp_9_s3/I0
12.326 | 0.469 | tINS | RR | 18 | R58C56[3][A] | g_sound.u_calib0/dclamp_9_s3/F
14.162 | 1.836 | tNET | RR | 1 | R55C53[1][A] | g_sound.u_calib0/dclamp_8_s1/I1
14.626 | 0.465 | tINS | RR | 3 | R55C53[1][A] | g_sound.u_calib0/dclamp_8_s1/F
14.773 | 0.146 | tNET | RR | 1 | R55C54[0][B] | g_sound.u_calib0/dclamp_8_s11/I1
15.246 | 0.474 | tINS | RR | 1 | R55C54[0][B] | g_sound.u_calib0/dclamp_8_s11/F
15.370 | 0.124 | tNET | RR | 1 | R55C54[1][A] | g_sound.u_calib0/dclamp_8_s6/I3
15.606 | 0.236 | tINS | RR | 5 | R55C54[1][A] | g_sound.u_calib0/dclamp_8_s6/F
15.928 | 0.322 | tNET | RR | 1 | R52C54[1][A] | g_sound.u_calib0/dclamp_2_s2/I1
16.402 | 0.474 | tINS | RR | 3 | R52C54[1][A] | g_sound.u_calib0/dclamp_2_s2/F
16.548 | 0.146 | tNET | RR | 1 | R52C55[3][A] | g_sound.u_calib0/dclamp_1_s0/I3
16.921 | 0.373 | tINS | RR | 1 | R52C55[3][A] | g_sound.u_calib0/dclamp_1_s0/F
17.866 | 0.945 | tNET | RR | 1 | DSP_R47[14] | g_sound.u_calib0/n909_s/A[1]

Data Required Path:

AT | DELAY | TYPE | RF | FANOUT | LOC | NODE
17.800 | 17.800 | | | | | active clock edge time
17.800 | 0.000 | | | | | clk_sys
17.800 | 0.000 | tCL | RR | 1 | IOB117[B] | clk_ibuf/I
19.088 | 1.288 | tINS | RR | 17287 | IOB117[B] | clk_ibuf/O
21.942 | 2.854 | tNET | RR | 1 | DSP_R47[14] | g_sound.u_calib0/n909_s/CLK[0]
18.562 | -3.379 | tSu | | 1 | DSP_R47[14] | g_sound.u_calib0/n909_s

Path Statistics:

Clock Skew | -0.008
Setup Relationship | 17.800
Logic Level | 11
Arrival Clock Path Delay | cell: 1.288, 31.042%; route: 2.862, 68.958%
Arrival Data Path Delay | cell: 4.546, 33.145%; route: 8.826, 64.345%; tC2Q: 0.344, 2.510%
Required Clock Path Delay | cell: 1.288, 31.105%; route: 2.854, 68.895%

### Path13

Path Summary:

Slack | 0.735
Data Arrival Time | 17.807
Data Required Time | 18.541
From | g_sound.u_adc_farm/u_scan0/sample_channel_0_s0
To | g_sound.u_calib0/n909_s
Launch Clk | clk_sys:[R]
Latch Clk | clk_sys:[R]

Data Arrival Path:

AT | DELAY | TYPE | RF | FANOUT | LOC | NODE
0.000 | 0.000 | | | | | active clock edge time
0.000 | 0.000 | | | | | clk_sys
0.000 | 0.000 | tCL | RR | 1 | IOB117[B] | clk_ibuf/I
1.288 | 1.288 | tINS | RR | 17287 | IOB117[B] | clk_ibuf/O
4.150 | 2.862 | tNET | RR | 1 | R62C108[0][B] | g_sound.u_adc_farm/u_scan0/sample_channel_0_s0/CLK
4.495 | 0.344 | tC2Q | RR | 147 | R62C108[0][B] | g_sound.u_adc_farm/u_scan0/sample_channel_0_s0/Q
7.030 | 2.536 | tNET | RR | 1 | R64C56[0][A] | g_sound.u_calib0/n4_s16/I2
7.504 | 0.474 | tINS | RR | 1 | R64C56[0][A] | g_sound.u_calib0/n4_s16/F
7.504 | 0.000 | tNET | RR | 1 | R64C56[0][A] | g_sound.u_calib0/n4_s13/I0
7.627 | 0.123 | tINS | RR | 1 | R64C56[0][A] | g_sound.u_calib0/n4_s13/O
7.627 | 0.000 | tNET | RR | 1 | R64C56[0][B] | g_sound.u_calib0/n4_s11/I1
7.704 | 0.078 | tINS | RR | 51 | R64C56[0][B] | g_sound.u_calib0/n4_s11/O
9.299 | 1.595 | tNET | RR | 1 | R61C50[3][B] | g_sound.u_calib0/zero_rd_8_s2/I0
9.769 | 0.469 | tINS | RR | 5 | R61C50[3][B] | g_sound.u_calib0/zero_rd_8_s2/F
10.694 | 0.926 | tNET | RR | 1 | R58C56[0][B] | g_sound.u_calib0/dclamp_9_s11/I3
11.159 | 0.465 | tINS | RR | 1 | R58C56[0][B] | g_sound.u_calib0/dclamp_9_s11/F
11.283 | 0.124 | tNET | RR | 1 | R58C56[3][B] | g_sound.u_calib0/dclamp_9_s5/I1
11.731 | 0.448 | tINS | RR | 2 | R58C56[3][B] | g_sound.u_calib0/dclamp_9_s5/F
11.857 | 0.126 | tNET | RR | 1 | R58C56[3][A] | g_sound.u_calib0/dclamp_9_s3/I0
12.326 | 0.469 | tINS | RR | 18 | R58C56[3][A] | g_sound.u_calib0/dclamp_9_s3/F
14.162 | 1.836 | tNET | RR | 1 | R55C53[1][A] | g_sound.u_calib0/dclamp_8_s1/I1
14.626 | 0.465 | tINS | RR | 3 | R55C53[1][A] | g_sound.u_calib0/dclamp_8_s1/F
14.773 | 0.146 | tNET | RR | 1 | R55C54[0][B] | g_sound.u_calib0/dclamp_8_s11/I1
15.246 | 0.474 | tINS | RR | 1 | R55C54[0][B] | g_sound.u_calib0/dclamp_8_s11/F
15.370 | 0.124 | tNET | RR | 1 | R55C54[1][A] | g_sound.u_calib0/dclamp_8_s6/I3
15.606 | 0.236 | tINS | RR | 5 | R55C54[1][A] | g_sound.u_calib0/dclamp_8_s6/F
15.928 | 0.322 | tNET | RR | 1 | R52C54[1][A] | g_sound.u_calib0/dclamp_2_s2/I1
16.402 | 0.474 | tINS | RR | 3 | R52C54[1][A] | g_sound.u_calib0/dclamp_2_s2/F
16.528 | 0.126 | tNET | RR | 1 | R52C54[0][B] | g_sound.u_calib0/dclamp_2_s0/I3
17.001 | 0.474 | tINS | RR | 1 | R52C54[0][B] | g_sound.u_calib0/dclamp_2_s0/F
17.807 | 0.806 | tNET | RR | 1 | DSP_R47[14] | g_sound.u_calib0/n909_s/A[2]

Data Required Path:

AT | DELAY | TYPE | RF | FANOUT | LOC | NODE
17.800 | 17.800 | | | | | active clock edge time
17.800 | 0.000 | | | | | clk_sys
17.800 | 0.000 | tCL | RR | 1 | IOB117[B] | clk_ibuf/I
19.088 | 1.288 | tINS | RR | 17287 | IOB117[B] | clk_ibuf/O
21.942 | 2.854 | tNET | RR | 1 | DSP_R47[14] | g_sound.u_calib0/n909_s/CLK[0]
18.541 | -3.401 | tSu | | 1 | DSP_R47[14] | g_sound.u_calib0/n909_s

Path Statistics:

Clock Skew | -0.008
Setup Relationship | 17.800
Logic Level | 11
Arrival Clock Path Delay | cell: 1.288, 31.042%; route: 2.862, 68.958%
Arrival Data Path Delay | cell: 4.646, 34.023%; route: 8.666, 63.457%; tC2Q: 0.344, 2.521%
Required Clock Path Delay | cell: 1.288, 31.105%; route: 2.854, 68.895%

### Path14

Path Summary:

Slack | 0.752
Data Arrival Time | 17.896
Data Required Time | 18.648
From | g_sound.u_calib_span/cur_axis_o_3_s1
To | g_sound.u_calib1/n909_s
Launch Clk | clk_sys:[R]
Latch Clk | clk_sys:[R]

Data Arrival Path:

AT | DELAY | TYPE | RF | FANOUT | LOC | NODE
0.000 | 0.000 | | | | | active clock edge time
0.000 | 0.000 | | | | | clk_sys
0.000 | 0.000 | tCL | RR | 1 | IOB117[B] | clk_ibuf/I
1.288 | 1.288 | tINS | RR | 17287 | IOB117[B] | clk_ibuf/O
4.142 | 2.854 | tNET | RR | 1 | R58C113[0][B] | g_sound.u_calib_span/cur_axis_o_3_s1/CLK
4.473 | 0.331 | tC2Q | RF | 74 | R58C113[0][B] | g_sound.u_calib_span/cur_axis_o_3_s1/Q
6.570 | 2.097 | tNET | FF | 1 | R58C104[0][A] | n4583_s1/I2
7.034 | 0.465 | tINS | FR | 13 | R58C104[0][A] | n4583_s1/F
10.921 | 3.887 | tNET | RR | 1 | R70C43[3][A] | g_sound.u_calib1/dclamp_7_s26/I2
11.182 | 0.261 | tINS | RF | 1 | R70C43[3][A] | g_sound.u_calib1/dclamp_7_s26/F
11.310 | 0.128 | tNET | FF | 1 | R69C43[3][A] | g_sound.u_calib1/dclamp_7_s18/I3
11.684 | 0.373 | tINS | FR | 1 | R69C43[3][A] | g_sound.u_calib1/dclamp_7_s18/F
11.826 | 0.142 | tNET | RR | 1 | R68C43[2][B] | g_sound.u_calib1/dclamp_7_s16/I3
12.299 | 0.474 | tINS | RR | 1 | R68C43[2][B] | g_sound.u_calib1/dclamp_7_s16/F
12.302 | 0.002 | tNET | RR | 1 | R68C43[3][B] | g_sound.u_calib1/dclamp_7_s21/I0
12.749 | 0.448 | tINS | RR | 1 | R68C43[3][B] | g_sound.u_calib1/dclamp_7_s21/F
12.891 | 0.142 | tNET | RR | 1 | R68C44[1][B] | g_sound.u_calib1/dclamp_7_s10/I1
13.306 | 0.415 | tINS | RR | 2 | R68C44[1][B] | g_sound.u_calib1/dclamp_7_s10/F
13.311 | 0.005 | tNET | RR | 1 | R68C44[1][A] | g_sound.u_calib1/dclamp_7_s6/I0
13.775 | 0.465 | tINS | RR | 2 | R68C44[1][A] | g_sound.u_calib1/dclamp_7_s6/F
14.212 | 0.436 | tNET | RR | 1 | R70C43[2][B] | g_sound.u_calib1/dclamp_7_s4/I1
14.676 | 0.465 | tINS | RR | 3 | R70C43[2][B] | g_sound.u_calib1/dclamp_7_s4/F
14.823 | 0.146 | tNET | RR | 1 | R70C42[2][B] | g_sound.u_calib1/dclamp_8_s9/I3
15.296 | 0.474 | tINS | RR | 1 | R70C42[2][B] | g_sound.u_calib1/dclamp_8_s9/F
15.438 | 0.142 | tNET | RR | 1 | R70C43[0][A] | g_sound.u_calib1/dclamp_8_s7/I1
15.853 | 0.415 | tINS | RR | 2 | R70C43[0][A] | g_sound.u_calib1/dclamp_8_s7/F
15.997 | 0.144 | tNET | RR | 1 | R70C44[2][B] | g_sound.u_calib1/dclamp_8_s4/I1
16.462 | 0.465 | tINS | RR | 9 | R70C44[2][B] | g_sound.u_calib1/dclamp_8_s4/F
16.910 | 0.448 | tNET | RR | 1 | R71C43[1][B] | g_sound.u_calib1/dclamp_4_s0/I3
17.325 | 0.415 | tINS | RR | 1 | R71C43[1][B] | g_sound.u_calib1/dclamp_4_s0/F
17.896 | 0.572 | tNET | RR | 1 | DSP_R65[13] | g_sound.u_calib1/n909_s/A[4]

Data Required Path:

AT | DELAY | TYPE | RF | FANOUT | LOC | NODE
17.800 | 17.800 | | | | | active clock edge time
17.800 | 0.000 | | | | | clk_sys
17.800 | 0.000 | tCL | RR | 1 | IOB117[B] | clk_ibuf/I
19.088 | 1.288 | tINS | RR | 17287 | IOB117[B] | clk_ibuf/O
21.942 | 2.854 | tNET | RR | 1 | DSP_R65[13] | g_sound.u_calib1/n909_s/CLK[0]
18.648 | -3.294 | tSu | | 1 | DSP_R65[13] | g_sound.u_calib1/n909_s

Path Statistics:

Clock Skew | 0.000
Setup Relationship | 17.800
Logic Level | 13
Arrival Clock Path Delay | cell: 1.288, 31.105%; route: 2.854, 68.895%
Arrival Data Path Delay | cell: 5.133, 37.322%; route: 8.290, 60.273%; tC2Q: 0.331, 2.405%
Required Clock Path Delay | cell: 1.288, 31.105%; route: 2.854, 68.895%

### Path15

Path Summary:

Slack | 0.765
Data Arrival Time | 21.116
Data Required Time | 21.882
From | g_sound.u_fader_gear/gear_o_0_s0
To | g_sound.u_vibrato_lfo/rate_inc_q_27_s0
Launch Clk | clk_sys:[R]
Latch Clk | clk_sys:[R]

Data Arrival Path:

AT | DELAY | TYPE | RF | FANOUT | LOC | NODE
0.000 | 0.000 | | | | | active clock edge time
0.000 | 0.000 | | | | | clk_sys
0.000 | 0.000 | tCL | RR | 1 | IOB117[B] | clk_ibuf/I
1.288 | 1.288 | tINS | RR | 17287 | IOB117[B] | clk_ibuf/O
4.142 | 2.854 | tNET | RR | 1 | R60C109[0][A] | g_sound.u_fader_gear/gear_o_0_s0/CLK
4.486 | 0.344 | tC2Q | RR | 23 | R60C109[0][A] | g_sound.u_fader_gear/gear_o_0_s0/Q
6.011 | 1.524 | tNET | RR | 1 | R66C119[3][B] | g_sound.u_fader_gear/g_sound.vib_rate_sel_0_s/I0
6.458 | 0.448 | tINS | RR | 1 | R66C119[3][B] | g_sound.u_fader_gear/g_sound.vib_rate_sel_0_s/F
7.519 | 1.061 | tNET | RR | 97 | DSP_R65[31] | g_sound.u_vibrato_lfo/rate_product_0_s/A[0]
10.176 | 2.657 | tINS | RR | 3 | DSP_R65[31] | g_sound.u_vibrato_lfo/rate_product_0_s/DOUT[15]
11.142 | 0.966 | tNET | RR | 1 | R68C116[0][A] | g_sound.u_vibrato_lfo/rate_target_w_5_s3/I2
11.607 | 0.465 | tINS | RR | 3 | R68C116[0][A] | g_sound.u_vibrato_lfo/rate_target_w_5_s3/F
11.753 | 0.146 | tNET | RR | 1 | R69C116[2][B] | g_sound.u_vibrato_lfo/rate_target_w_8_s3/I0
12.218 | 0.465 | tINS | RR | 4 | R69C116[2][B] | g_sound.u_vibrato_lfo/rate_target_w_8_s3/F
12.537 | 0.319 | tNET | RR | 1 | R68C117[2][A] | g_sound.u_vibrato_lfo/rate_target_w_9_s2/I1
13.002 | 0.465 | tINS | RR | 8 | R68C117[2][A] | g_sound.u_vibrato_lfo/rate_target_w_9_s2/F
13.614 | 0.612 | tNET | RR | 2 | R71C116[1][B] | g_sound.u_vibrato_lfo/n462_s/I0
14.114 | 0.501 | tINS | RF | 1 | R71C116[1][B] | g_sound.u_vibrato_lfo/n462_s/COUT
14.114 | 0.000 | tNET | FF | 2 | R71C116[2][A] | g_sound.u_vibrato_lfo/n461_s/CIN
14.159 | 0.045 | tINS | FR | 1 | R71C116[2][A] | g_sound.u_vibrato_lfo/n461_s/COUT
14.159 | 0.000 | tNET | RR | 2 | R71C116[2][B] | g_sound.u_vibrato_lfo/n460_s/CIN
14.204 | 0.045 | tINS | RR | 1 | R71C116[2][B] | g_sound.u_vibrato_lfo/n460_s/COUT
14.204 | 0.000 | tNET | RR | 2 | R71C117[0][A] | g_sound.u_vibrato_lfo/n459_s/CIN
14.249 | 0.045 | tINS | RR | 1 | R71C117[0][A] | g_sound.u_vibrato_lfo/n459_s/COUT
14.249 | 0.000 | tNET | RR | 2 | R71C117[0][B] | g_sound.u_vibrato_lfo/n458_s/CIN
14.294 | 0.045 | tINS | RR | 1 | R71C117[0][B] | g_sound.u_vibrato_lfo/n458_s/COUT
14.294 | 0.000 | tNET | RR | 2 | R71C117[1][A] | g_sound.u_vibrato_lfo/n457_s/CIN
14.339 | 0.045 | tINS | RR | 1 | R71C117[1][A] | g_sound.u_vibrato_lfo/n457_s/COUT
14.339 | 0.000 | tNET | RR | 2 | R71C117[1][B] | g_sound.u_vibrato_lfo/n456_s/CIN
14.384 | 0.045 | tINS | RR | 1 | R71C117[1][B] | g_sound.u_vibrato_lfo/n456_s/COUT
14.384 | 0.000 | tNET | RR | 2 | R71C117[2][A] | g_sound.u_vibrato_lfo/n455_s/CIN
14.429 | 0.045 | tINS | RR | 1 | R71C117[2][A] | g_sound.u_vibrato_lfo/n455_s/COUT
14.429 | 0.000 | tNET | RR | 2 | R71C117[2][B] | g_sound.u_vibrato_lfo/n454_s/CIN
14.474 | 0.045 | tINS | RR | 1 | R71C117[2][B] | g_sound.u_vibrato_lfo/n454_s/COUT
14.474 | 0.000 | tNET | RR | 2 | R71C118[0][A] | g_sound.u_vibrato_lfo/n453_s/CIN
14.519 | 0.045 | tINS | RR | 1 | R71C118[0][A] | g_sound.u_vibrato_lfo/n453_s/COUT
14.519 | 0.000 | tNET | RR | 2 | R71C118[0][B] | g_sound.u_vibrato_lfo/n452_s/CIN
14.564 | 0.045 | tINS | RR | 1 | R71C118[0][B] | g_sound.u_vibrato_lfo/n452_s/COUT
14.564 | 0.000 | tNET | RR | 2 | R71C118[1][A] | g_sound.u_vibrato_lfo/n451_s/CIN
14.609 | 0.045 | tINS | RR | 1 | R71C118[1][A] | g_sound.u_vibrato_lfo/n451_s/COUT
14.609 | 0.000 | tNET | RR | 2 | R71C118[1][B] | g_sound.u_vibrato_lfo/n450_s/CIN
14.654 | 0.045 | tINS | RR | 1 | R71C118[1][B] | g_sound.u_vibrato_lfo/n450_s/COUT
14.654 | 0.000 | tNET | RR | 2 | R71C118[2][A] | g_sound.u_vibrato_lfo/n449_s/CIN
14.699 | 0.045 | tINS | RR | 1 | R71C118[2][A] | g_sound.u_vibrato_lfo/n449_s/COUT
14.699 | 0.000 | tNET | RR | 2 | R71C118[2][B] | g_sound.u_vibrato_lfo/n448_s/CIN
14.970 | 0.271 | tINS | RF | 1 | R71C118[2][B] | g_sound.u_vibrato_lfo/n448_s/SUM
14.975 | 0.005 | tNET | FF | 1 | R71C118[3][A] | g_sound.u_vibrato_lfo/n651_s19/I1
15.423 | 0.448 | tINS | FR | 1 | R71C118[3][A] | g_sound.u_vibrato_lfo/n651_s19/F
15.425 | 0.002 | tNET | RR | 1 | R71C118[3][B] | g_sound.u_vibrato_lfo/n651_s18/I3
15.798 | 0.373 | tINS | RR | 1 | R71C118[3][B] | g_sound.u_vibrato_lfo/n651_s18/F
16.111 | 0.313 | tNET | RR | 1 | R72C116[0][B] | g_sound.u_vibrato_lfo/n651_s15/I3
16.526 | 0.415 | tINS | RR | 1 | R72C116[0][B] | g_sound.u_vibrato_lfo/n651_s15/F
16.821 | 0.295 | tNET | RR | 1 | R71C116[3][A] | g_sound.u_vibrato_lfo/n651_s11/I3
17.290 | 0.469 | tINS | RR | 1 | R71C116[3][A] | g_sound.u_vibrato_lfo/n651_s11/F
17.657 | 0.367 | tNET | RR | 1 | R71C119[3][B] | g_sound.u_vibrato_lfo/n651_s7/I3
18.105 | 0.448 | tINS | RR | 4 | R71C119[3][B] | g_sound.u_vibrato_lfo/n651_s7/F
18.820 | 0.715 | tNET | RR | 1 | R72C115[1][B] | g_sound.u_vibrato_lfo/n651_s2/I0
19.294 | 0.474 | tINS | RR | 19 | R72C115[1][B] | g_sound.u_vibrato_lfo/n651_s2/F
20.855 | 1.561 | tNET | RR | 1 | R73C122[3][A] | g_sound.u_vibrato_lfo/n666_s0/I0
21.116 | 0.261 | tINS | RF | 1 | R73C122[3][A] | g_sound.u_vibrato_lfo/n666_s0/F
21.116 | 0.000 | tNET | FF | 1 | R73C122[3][A] | g_sound.u_vibrato_lfo/rate_inc_q_27_s0/D

Data Required Path:

AT | DELAY | TYPE | RF | FANOUT | LOC | NODE
17.800 | 17.800 | | | | | active clock edge time
17.800 | 0.000 | | | | | clk_sys
17.800 | 0.000 | tCL | RR | 1 | IOB117[B] | clk_ibuf/I
19.088 | 1.288 | tINS | RR | 17287 | IOB117[B] | clk_ibuf/O
21.933 | 2.845 | tNET | RR | 1 | R73C122[3][A] | g_sound.u_vibrato_lfo/rate_inc_q_27_s0/CLK
21.882 | -0.052 | tSu | | 1 | R73C122[3][A] | g_sound.u_vibrato_lfo/rate_inc_q_27_s0

Path Statistics:

Clock Skew | -0.008
Setup Relationship | 17.800
Logic Level | 16
Arrival Clock Path Delay | cell: 1.288, 31.105%; route: 2.854, 68.895%
Arrival Data Path Delay | cell: 8.743, 51.506%; route: 7.887, 46.466%; tC2Q: 0.344, 2.028%
Required Clock Path Delay | cell: 1.288, 31.169%; route: 2.845, 68.831%

### Path16

Path Summary:

Slack | 0.792
Data Arrival Time | 18.045
Data Required Time | 18.837
From | g_sound.u_adc_farm/u_scan0/sample_channel_0_s0
To | g_sound.u_calib0/n909_s
Launch Clk | clk_sys:[R]
Latch Clk | clk_sys:[R]

Data Arrival Path:

AT | DELAY | TYPE | RF | FANOUT | LOC | NODE
0.000 | 0.000 | | | | | active clock edge time
0.000 | 0.000 | | | | | clk_sys
0.000 | 0.000 | tCL | RR | 1 | IOB117[B] | clk_ibuf/I
1.288 | 1.288 | tINS | RR | 17287 | IOB117[B] | clk_ibuf/O
4.150 | 2.862 | tNET | RR | 1 | R62C108[0][B] | g_sound.u_adc_farm/u_scan0/sample_channel_0_s0/CLK
4.495 | 0.344 | tC2Q | RR | 147 | R62C108[0][B] | g_sound.u_adc_farm/u_scan0/sample_channel_0_s0/Q
7.030 | 2.536 | tNET | RR | 1 | R64C56[0][A] | g_sound.u_calib0/n4_s16/I2
7.504 | 0.474 | tINS | RR | 1 | R64C56[0][A] | g_sound.u_calib0/n4_s16/F
7.504 | 0.000 | tNET | RR | 1 | R64C56[0][A] | g_sound.u_calib0/n4_s13/I0
7.627 | 0.123 | tINS | RR | 1 | R64C56[0][A] | g_sound.u_calib0/n4_s13/O
7.627 | 0.000 | tNET | RR | 1 | R64C56[0][B] | g_sound.u_calib0/n4_s11/I1
7.704 | 0.078 | tINS | RR | 51 | R64C56[0][B] | g_sound.u_calib0/n4_s11/O
9.299 | 1.595 | tNET | RR | 1 | R61C50[3][B] | g_sound.u_calib0/zero_rd_8_s2/I0
9.769 | 0.469 | tINS | RR | 5 | R61C50[3][B] | g_sound.u_calib0/zero_rd_8_s2/F
10.694 | 0.926 | tNET | RR | 1 | R58C56[0][B] | g_sound.u_calib0/dclamp_9_s11/I3
11.159 | 0.465 | tINS | RR | 1 | R58C56[0][B] | g_sound.u_calib0/dclamp_9_s11/F
11.283 | 0.124 | tNET | RR | 1 | R58C56[3][B] | g_sound.u_calib0/dclamp_9_s5/I1
11.731 | 0.448 | tINS | RR | 2 | R58C56[3][B] | g_sound.u_calib0/dclamp_9_s5/F
11.857 | 0.126 | tNET | RR | 1 | R58C56[3][A] | g_sound.u_calib0/dclamp_9_s3/I0
12.326 | 0.469 | tINS | RR | 18 | R58C56[3][A] | g_sound.u_calib0/dclamp_9_s3/F
14.162 | 1.836 | tNET | RR | 1 | R55C53[1][A] | g_sound.u_calib0/dclamp_8_s1/I1
14.626 | 0.465 | tINS | RR | 3 | R55C53[1][A] | g_sound.u_calib0/dclamp_8_s1/F
14.773 | 0.146 | tNET | RR | 1 | R55C54[0][A] | g_sound.u_calib0/dclamp_8_s13/I1
15.246 | 0.474 | tINS | RR | 2 | R55C54[0][A] | g_sound.u_calib0/dclamp_8_s13/F
15.390 | 0.144 | tNET | RR | 1 | R54C54[0][A] | g_sound.u_calib0/dclamp_8_s7/I1
15.864 | 0.474 | tINS | RR | 4 | R54C54[0][A] | g_sound.u_calib0/dclamp_8_s7/F
16.286 | 0.422 | tNET | RR | 1 | R57C54[0][B] | g_sound.u_calib0/dclamp_7_s3/I3
16.750 | 0.465 | tINS | RR | 1 | R57C54[0][B] | g_sound.u_calib0/dclamp_7_s3/F
16.753 | 0.002 | tNET | RR | 1 | R57C54[2][B] | g_sound.u_calib0/dclamp_7_s0/I3
17.217 | 0.465 | tINS | RR | 1 | R57C54[2][B] | g_sound.u_calib0/dclamp_7_s0/F
18.045 | 0.828 | tNET | RR | 1 | DSP_R47[14] | g_sound.u_calib0/n909_s/A[7]

Data Required Path:

AT | DELAY | TYPE | RF | FANOUT | LOC | NODE
17.800 | 17.800 | | | | | active clock edge time
17.800 | 0.000 | | | | | clk_sys
17.800 | 0.000 | tCL | RR | 1 | IOB117[B] | clk_ibuf/I
19.088 | 1.288 | tINS | RR | 17287 | IOB117[B] | clk_ibuf/O
21.942 | 2.854 | tNET | RR | 1 | DSP_R47[14] | g_sound.u_calib0/n909_s/CLK[0]
18.837 | -3.105 | tSu | | 1 | DSP_R47[14] | g_sound.u_calib0/n909_s

Path Statistics:

Clock Skew | -0.008
Setup Relationship | 17.800
Logic Level | 11
Arrival Clock Path Delay | cell: 1.288, 31.042%; route: 2.862, 68.958%
Arrival Data Path Delay | cell: 4.866, 35.017%; route: 8.685, 62.505%; tC2Q: 0.344, 2.478%
Required Clock Path Delay | cell: 1.288, 31.105%; route: 2.854, 68.895%

### Path17

Path Summary:

Slack | 0.807
Data Arrival Time | 17.885
Data Required Time | 18.692
From | g_sound.u_calib_span/cur_axis_o_3_s1
To | g_sound.u_calib1/n909_s
Launch Clk | clk_sys:[R]
Latch Clk | clk_sys:[R]

Data Arrival Path:

AT | DELAY | TYPE | RF | FANOUT | LOC | NODE
0.000 | 0.000 | | | | | active clock edge time
0.000 | 0.000 | | | | | clk_sys
0.000 | 0.000 | tCL | RR | 1 | IOB117[B] | clk_ibuf/I
1.288 | 1.288 | tINS | RR | 17287 | IOB117[B] | clk_ibuf/O
4.142 | 2.854 | tNET | RR | 1 | R58C113[0][B] | g_sound.u_calib_span/cur_axis_o_3_s1/CLK
4.473 | 0.331 | tC2Q | RF | 74 | R58C113[0][B] | g_sound.u_calib_span/cur_axis_o_3_s1/Q
6.570 | 2.097 | tNET | FF | 1 | R58C104[0][A] | n4583_s1/I2
7.034 | 0.465 | tINS | FR | 13 | R58C104[0][A] | n4583_s1/F
10.921 | 3.887 | tNET | RR | 1 | R70C43[3][A] | g_sound.u_calib1/dclamp_7_s26/I2
11.182 | 0.261 | tINS | RF | 1 | R70C43[3][A] | g_sound.u_calib1/dclamp_7_s26/F
11.310 | 0.128 | tNET | FF | 1 | R69C43[3][A] | g_sound.u_calib1/dclamp_7_s18/I3
11.684 | 0.373 | tINS | FR | 1 | R69C43[3][A] | g_sound.u_calib1/dclamp_7_s18/F
11.826 | 0.142 | tNET | RR | 1 | R68C43[2][B] | g_sound.u_calib1/dclamp_7_s16/I3
12.299 | 0.474 | tINS | RR | 1 | R68C43[2][B] | g_sound.u_calib1/dclamp_7_s16/F
12.302 | 0.002 | tNET | RR | 1 | R68C43[3][B] | g_sound.u_calib1/dclamp_7_s21/I0
12.749 | 0.448 | tINS | RR | 1 | R68C43[3][B] | g_sound.u_calib1/dclamp_7_s21/F
12.891 | 0.142 | tNET | RR | 1 | R68C44[1][B] | g_sound.u_calib1/dclamp_7_s10/I1
13.306 | 0.415 | tINS | RR | 2 | R68C44[1][B] | g_sound.u_calib1/dclamp_7_s10/F
13.311 | 0.005 | tNET | RR | 1 | R68C44[1][A] | g_sound.u_calib1/dclamp_7_s6/I0
13.775 | 0.465 | tINS | RR | 2 | R68C44[1][A] | g_sound.u_calib1/dclamp_7_s6/F
14.212 | 0.436 | tNET | RR | 1 | R70C43[2][B] | g_sound.u_calib1/dclamp_7_s4/I1
14.676 | 0.465 | tINS | RR | 3 | R70C43[2][B] | g_sound.u_calib1/dclamp_7_s4/F
14.823 | 0.146 | tNET | RR | 1 | R70C42[2][B] | g_sound.u_calib1/dclamp_8_s9/I3
15.296 | 0.474 | tINS | RR | 1 | R70C42[2][B] | g_sound.u_calib1/dclamp_8_s9/F
15.438 | 0.142 | tNET | RR | 1 | R70C43[0][A] | g_sound.u_calib1/dclamp_8_s7/I1
15.853 | 0.415 | tINS | RR | 2 | R70C43[0][A] | g_sound.u_calib1/dclamp_8_s7/F
15.997 | 0.144 | tNET | RR | 1 | R70C44[2][B] | g_sound.u_calib1/dclamp_8_s4/I1
16.462 | 0.465 | tINS | RR | 9 | R70C44[2][B] | g_sound.u_calib1/dclamp_8_s4/F
16.784 | 0.322 | tNET | RR | 1 | R71C43[0][A] | g_sound.u_calib1/dclamp_5_s0/I3
17.248 | 0.465 | tINS | RR | 1 | R71C43[0][A] | g_sound.u_calib1/dclamp_5_s0/F
17.885 | 0.637 | tNET | RR | 1 | DSP_R65[13] | g_sound.u_calib1/n909_s/A[5]

Data Required Path:

AT | DELAY | TYPE | RF | FANOUT | LOC | NODE
17.800 | 17.800 | | | | | active clock edge time
17.800 | 0.000 | | | | | clk_sys
17.800 | 0.000 | tCL | RR | 1 | IOB117[B] | clk_ibuf/I
19.088 | 1.288 | tINS | RR | 17287 | IOB117[B] | clk_ibuf/O
21.942 | 2.854 | tNET | RR | 1 | DSP_R65[13] | g_sound.u_calib1/n909_s/CLK[0]
18.692 | -3.250 | tSu | | 1 | DSP_R65[13] | g_sound.u_calib1/n909_s

Path Statistics:

Clock Skew | 0.000
Setup Relationship | 17.800
Logic Level | 13
Arrival Clock Path Delay | cell: 1.288, 31.105%; route: 2.854, 68.895%
Arrival Data Path Delay | cell: 5.183, 37.713%; route: 8.229, 59.880%; tC2Q: 0.331, 2.407%
Required Clock Path Delay | cell: 1.288, 31.105%; route: 2.854, 68.895%

### Path18

Path Summary:

Slack | 0.827
Data Arrival Time | 21.058
Data Required Time | 21.885
From | g_sound.u_fader_gear/gear_o_0_s0
To | g_sound.u_vibrato_lfo/rate_inc_q_28_s0
Launch Clk | clk_sys:[R]
Latch Clk | clk_sys:[R]

Data Arrival Path:

AT | DELAY | TYPE | RF | FANOUT | LOC | NODE
0.000 | 0.000 | | | | | active clock edge time
0.000 | 0.000 | | | | | clk_sys
0.000 | 0.000 | tCL | RR | 1 | IOB117[B] | clk_ibuf/I
1.288 | 1.288 | tINS | RR | 17287 | IOB117[B] | clk_ibuf/O
4.142 | 2.854 | tNET | RR | 1 | R60C109[0][A] | g_sound.u_fader_gear/gear_o_0_s0/CLK
4.486 | 0.344 | tC2Q | RR | 23 | R60C109[0][A] | g_sound.u_fader_gear/gear_o_0_s0/Q
6.011 | 1.524 | tNET | RR | 1 | R66C119[3][B] | g_sound.u_fader_gear/g_sound.vib_rate_sel_0_s/I0
6.458 | 0.448 | tINS | RR | 1 | R66C119[3][B] | g_sound.u_fader_gear/g_sound.vib_rate_sel_0_s/F
7.519 | 1.061 | tNET | RR | 97 | DSP_R65[31] | g_sound.u_vibrato_lfo/rate_product_0_s/A[0]
10.176 | 2.657 | tINS | RR | 3 | DSP_R65[31] | g_sound.u_vibrato_lfo/rate_product_0_s/DOUT[15]
11.142 | 0.966 | tNET | RR | 1 | R68C116[0][A] | g_sound.u_vibrato_lfo/rate_target_w_5_s3/I2
11.607 | 0.465 | tINS | RR | 3 | R68C116[0][A] | g_sound.u_vibrato_lfo/rate_target_w_5_s3/F
11.753 | 0.146 | tNET | RR | 1 | R69C116[2][B] | g_sound.u_vibrato_lfo/rate_target_w_8_s3/I0
12.218 | 0.465 | tINS | RR | 4 | R69C116[2][B] | g_sound.u_vibrato_lfo/rate_target_w_8_s3/F
12.537 | 0.319 | tNET | RR | 1 | R68C117[2][A] | g_sound.u_vibrato_lfo/rate_target_w_9_s2/I1
13.002 | 0.465 | tINS | RR | 8 | R68C117[2][A] | g_sound.u_vibrato_lfo/rate_target_w_9_s2/F
13.614 | 0.612 | tNET | RR | 2 | R71C116[1][B] | g_sound.u_vibrato_lfo/n462_s/I0
14.114 | 0.501 | tINS | RF | 1 | R71C116[1][B] | g_sound.u_vibrato_lfo/n462_s/COUT
14.114 | 0.000 | tNET | FF | 2 | R71C116[2][A] | g_sound.u_vibrato_lfo/n461_s/CIN
14.159 | 0.045 | tINS | FR | 1 | R71C116[2][A] | g_sound.u_vibrato_lfo/n461_s/COUT
14.159 | 0.000 | tNET | RR | 2 | R71C116[2][B] | g_sound.u_vibrato_lfo/n460_s/CIN
14.204 | 0.045 | tINS | RR | 1 | R71C116[2][B] | g_sound.u_vibrato_lfo/n460_s/COUT
14.204 | 0.000 | tNET | RR | 2 | R71C117[0][A] | g_sound.u_vibrato_lfo/n459_s/CIN
14.249 | 0.045 | tINS | RR | 1 | R71C117[0][A] | g_sound.u_vibrato_lfo/n459_s/COUT
14.249 | 0.000 | tNET | RR | 2 | R71C117[0][B] | g_sound.u_vibrato_lfo/n458_s/CIN
14.294 | 0.045 | tINS | RR | 1 | R71C117[0][B] | g_sound.u_vibrato_lfo/n458_s/COUT
14.294 | 0.000 | tNET | RR | 2 | R71C117[1][A] | g_sound.u_vibrato_lfo/n457_s/CIN
14.339 | 0.045 | tINS | RR | 1 | R71C117[1][A] | g_sound.u_vibrato_lfo/n457_s/COUT
14.339 | 0.000 | tNET | RR | 2 | R71C117[1][B] | g_sound.u_vibrato_lfo/n456_s/CIN
14.384 | 0.045 | tINS | RR | 1 | R71C117[1][B] | g_sound.u_vibrato_lfo/n456_s/COUT
14.384 | 0.000 | tNET | RR | 2 | R71C117[2][A] | g_sound.u_vibrato_lfo/n455_s/CIN
14.429 | 0.045 | tINS | RR | 1 | R71C117[2][A] | g_sound.u_vibrato_lfo/n455_s/COUT
14.429 | 0.000 | tNET | RR | 2 | R71C117[2][B] | g_sound.u_vibrato_lfo/n454_s/CIN
14.474 | 0.045 | tINS | RR | 1 | R71C117[2][B] | g_sound.u_vibrato_lfo/n454_s/COUT
14.474 | 0.000 | tNET | RR | 2 | R71C118[0][A] | g_sound.u_vibrato_lfo/n453_s/CIN
14.519 | 0.045 | tINS | RR | 1 | R71C118[0][A] | g_sound.u_vibrato_lfo/n453_s/COUT
14.519 | 0.000 | tNET | RR | 2 | R71C118[0][B] | g_sound.u_vibrato_lfo/n452_s/CIN
14.564 | 0.045 | tINS | RR | 1 | R71C118[0][B] | g_sound.u_vibrato_lfo/n452_s/COUT
14.564 | 0.000 | tNET | RR | 2 | R71C118[1][A] | g_sound.u_vibrato_lfo/n451_s/CIN
14.609 | 0.045 | tINS | RR | 1 | R71C118[1][A] | g_sound.u_vibrato_lfo/n451_s/COUT
14.609 | 0.000 | tNET | RR | 2 | R71C118[1][B] | g_sound.u_vibrato_lfo/n450_s/CIN
14.654 | 0.045 | tINS | RR | 1 | R71C118[1][B] | g_sound.u_vibrato_lfo/n450_s/COUT
14.654 | 0.000 | tNET | RR | 2 | R71C118[2][A] | g_sound.u_vibrato_lfo/n449_s/CIN
14.699 | 0.045 | tINS | RR | 1 | R71C118[2][A] | g_sound.u_vibrato_lfo/n449_s/COUT
14.699 | 0.000 | tNET | RR | 2 | R71C118[2][B] | g_sound.u_vibrato_lfo/n448_s/CIN
14.970 | 0.271 | tINS | RF | 1 | R71C118[2][B] | g_sound.u_vibrato_lfo/n448_s/SUM
14.975 | 0.005 | tNET | FF | 1 | R71C118[3][A] | g_sound.u_vibrato_lfo/n651_s19/I1
15.423 | 0.448 | tINS | FR | 1 | R71C118[3][A] | g_sound.u_vibrato_lfo/n651_s19/F
15.425 | 0.002 | tNET | RR | 1 | R71C118[3][B] | g_sound.u_vibrato_lfo/n651_s18/I3
15.798 | 0.373 | tINS | RR | 1 | R71C118[3][B] | g_sound.u_vibrato_lfo/n651_s18/F
16.111 | 0.313 | tNET | RR | 1 | R72C116[0][B] | g_sound.u_vibrato_lfo/n651_s15/I3
16.526 | 0.415 | tINS | RR | 1 | R72C116[0][B] | g_sound.u_vibrato_lfo/n651_s15/F
16.821 | 0.295 | tNET | RR | 1 | R71C116[3][A] | g_sound.u_vibrato_lfo/n651_s11/I3
17.290 | 0.469 | tINS | RR | 1 | R71C116[3][A] | g_sound.u_vibrato_lfo/n651_s11/F
17.657 | 0.367 | tNET | RR | 1 | R71C119[3][B] | g_sound.u_vibrato_lfo/n651_s7/I3
18.105 | 0.448 | tINS | RR | 4 | R71C119[3][B] | g_sound.u_vibrato_lfo/n651_s7/F
18.820 | 0.715 | tNET | RR | 1 | R72C115[1][B] | g_sound.u_vibrato_lfo/n651_s2/I0
19.294 | 0.474 | tINS | RR | 19 | R72C115[1][B] | g_sound.u_vibrato_lfo/n651_s2/F
20.684 | 1.390 | tNET | RR | 1 | R73C121[3][A] | g_sound.u_vibrato_lfo/n665_s0/I0
21.058 | 0.373 | tINS | RR | 1 | R73C121[3][A] | g_sound.u_vibrato_lfo/n665_s0/F
21.058 | 0.000 | tNET | RR | 1 | R73C121[3][A] | g_sound.u_vibrato_lfo/rate_inc_q_28_s0/D

Data Required Path:

AT | DELAY | TYPE | RF | FANOUT | LOC | NODE
17.800 | 17.800 | | | | | active clock edge time
17.800 | 0.000 | | | | | clk_sys
17.800 | 0.000 | tCL | RR | 1 | IOB117[B] | clk_ibuf/I
19.088 | 1.288 | tINS | RR | 17287 | IOB117[B] | clk_ibuf/O
21.942 | 2.854 | tNET | RR | 1 | R73C121[3][A] | g_sound.u_vibrato_lfo/rate_inc_q_28_s0/CLK
21.885 | -0.057 | tSu | | 1 | R73C121[3][A] | g_sound.u_vibrato_lfo/rate_inc_q_28_s0

Path Statistics:

Clock Skew | 0.000
Setup Relationship | 17.800
Logic Level | 16
Arrival Clock Path Delay | cell: 1.288, 31.105%; route: 2.854, 68.895%
Arrival Data Path Delay | cell: 8.855, 52.349%; route: 7.716, 45.616%; tC2Q: 0.344, 2.035%
Required Clock Path Delay | cell: 1.288, 31.105%; route: 2.854, 68.895%

### Path19

Path Summary:

Slack | 0.891
Data Arrival Time | 20.994
Data Required Time | 21.885
From | g_sound.u_fader_gear/gear_o_0_s0
To | g_sound.u_vibrato_lfo/rate_inc_q_9_s0
Launch Clk | clk_sys:[R]
Latch Clk | clk_sys:[R]

Data Arrival Path:

AT | DELAY | TYPE | RF | FANOUT | LOC | NODE
0.000 | 0.000 | | | | | active clock edge time
0.000 | 0.000 | | | | | clk_sys
0.000 | 0.000 | tCL | RR | 1 | IOB117[B] | clk_ibuf/I
1.288 | 1.288 | tINS | RR | 17287 | IOB117[B] | clk_ibuf/O
4.142 | 2.854 | tNET | RR | 1 | R60C109[0][A] | g_sound.u_fader_gear/gear_o_0_s0/CLK
4.486 | 0.344 | tC2Q | RR | 23 | R60C109[0][A] | g_sound.u_fader_gear/gear_o_0_s0/Q
6.011 | 1.524 | tNET | RR | 1 | R66C119[3][B] | g_sound.u_fader_gear/g_sound.vib_rate_sel_0_s/I0
6.458 | 0.448 | tINS | RR | 1 | R66C119[3][B] | g_sound.u_fader_gear/g_sound.vib_rate_sel_0_s/F
7.519 | 1.061 | tNET | RR | 97 | DSP_R65[31] | g_sound.u_vibrato_lfo/rate_product_0_s/A[0]
10.176 | 2.657 | tINS | RR | 3 | DSP_R65[31] | g_sound.u_vibrato_lfo/rate_product_0_s/DOUT[15]
11.142 | 0.966 | tNET | RR | 1 | R68C116[0][A] | g_sound.u_vibrato_lfo/rate_target_w_5_s3/I2
11.607 | 0.465 | tINS | RR | 3 | R68C116[0][A] | g_sound.u_vibrato_lfo/rate_target_w_5_s3/F
11.753 | 0.146 | tNET | RR | 1 | R69C116[2][B] | g_sound.u_vibrato_lfo/rate_target_w_8_s3/I0
12.218 | 0.465 | tINS | RR | 4 | R69C116[2][B] | g_sound.u_vibrato_lfo/rate_target_w_8_s3/F
12.537 | 0.319 | tNET | RR | 1 | R68C117[2][A] | g_sound.u_vibrato_lfo/rate_target_w_9_s2/I1
13.002 | 0.465 | tINS | RR | 8 | R68C117[2][A] | g_sound.u_vibrato_lfo/rate_target_w_9_s2/F
13.614 | 0.612 | tNET | RR | 2 | R71C116[1][B] | g_sound.u_vibrato_lfo/n462_s/I0
14.114 | 0.501 | tINS | RF | 1 | R71C116[1][B] | g_sound.u_vibrato_lfo/n462_s/COUT
14.114 | 0.000 | tNET | FF | 2 | R71C116[2][A] | g_sound.u_vibrato_lfo/n461_s/CIN
14.159 | 0.045 | tINS | FR | 1 | R71C116[2][A] | g_sound.u_vibrato_lfo/n461_s/COUT
14.159 | 0.000 | tNET | RR | 2 | R71C116[2][B] | g_sound.u_vibrato_lfo/n460_s/CIN
14.204 | 0.045 | tINS | RR | 1 | R71C116[2][B] | g_sound.u_vibrato_lfo/n460_s/COUT
14.204 | 0.000 | tNET | RR | 2 | R71C117[0][A] | g_sound.u_vibrato_lfo/n459_s/CIN
14.249 | 0.045 | tINS | RR | 1 | R71C117[0][A] | g_sound.u_vibrato_lfo/n459_s/COUT
14.249 | 0.000 | tNET | RR | 2 | R71C117[0][B] | g_sound.u_vibrato_lfo/n458_s/CIN
14.294 | 0.045 | tINS | RR | 1 | R71C117[0][B] | g_sound.u_vibrato_lfo/n458_s/COUT
14.294 | 0.000 | tNET | RR | 2 | R71C117[1][A] | g_sound.u_vibrato_lfo/n457_s/CIN
14.339 | 0.045 | tINS | RR | 1 | R71C117[1][A] | g_sound.u_vibrato_lfo/n457_s/COUT
14.339 | 0.000 | tNET | RR | 2 | R71C117[1][B] | g_sound.u_vibrato_lfo/n456_s/CIN
14.384 | 0.045 | tINS | RR | 1 | R71C117[1][B] | g_sound.u_vibrato_lfo/n456_s/COUT
14.384 | 0.000 | tNET | RR | 2 | R71C117[2][A] | g_sound.u_vibrato_lfo/n455_s/CIN
14.429 | 0.045 | tINS | RR | 1 | R71C117[2][A] | g_sound.u_vibrato_lfo/n455_s/COUT
14.429 | 0.000 | tNET | RR | 2 | R71C117[2][B] | g_sound.u_vibrato_lfo/n454_s/CIN
14.474 | 0.045 | tINS | RR | 1 | R71C117[2][B] | g_sound.u_vibrato_lfo/n454_s/COUT
14.474 | 0.000 | tNET | RR | 2 | R71C118[0][A] | g_sound.u_vibrato_lfo/n453_s/CIN
14.519 | 0.045 | tINS | RR | 1 | R71C118[0][A] | g_sound.u_vibrato_lfo/n453_s/COUT
14.519 | 0.000 | tNET | RR | 2 | R71C118[0][B] | g_sound.u_vibrato_lfo/n452_s/CIN
14.564 | 0.045 | tINS | RR | 1 | R71C118[0][B] | g_sound.u_vibrato_lfo/n452_s/COUT
14.564 | 0.000 | tNET | RR | 2 | R71C118[1][A] | g_sound.u_vibrato_lfo/n451_s/CIN
14.609 | 0.045 | tINS | RR | 1 | R71C118[1][A] | g_sound.u_vibrato_lfo/n451_s/COUT
14.609 | 0.000 | tNET | RR | 2 | R71C118[1][B] | g_sound.u_vibrato_lfo/n450_s/CIN
14.654 | 0.045 | tINS | RR | 1 | R71C118[1][B] | g_sound.u_vibrato_lfo/n450_s/COUT
14.654 | 0.000 | tNET | RR | 2 | R71C118[2][A] | g_sound.u_vibrato_lfo/n449_s/CIN
14.699 | 0.045 | tINS | RR | 1 | R71C118[2][A] | g_sound.u_vibrato_lfo/n449_s/COUT
14.699 | 0.000 | tNET | RR | 2 | R71C118[2][B] | g_sound.u_vibrato_lfo/n448_s/CIN
14.970 | 0.271 | tINS | RF | 1 | R71C118[2][B] | g_sound.u_vibrato_lfo/n448_s/SUM
14.975 | 0.005 | tNET | FF | 1 | R71C118[3][A] | g_sound.u_vibrato_lfo/n651_s19/I1
15.423 | 0.448 | tINS | FR | 1 | R71C118[3][A] | g_sound.u_vibrato_lfo/n651_s19/F
15.425 | 0.002 | tNET | RR | 1 | R71C118[3][B] | g_sound.u_vibrato_lfo/n651_s18/I3
15.798 | 0.373 | tINS | RR | 1 | R71C118[3][B] | g_sound.u_vibrato_lfo/n651_s18/F
16.111 | 0.313 | tNET | RR | 1 | R72C116[0][B] | g_sound.u_vibrato_lfo/n651_s15/I3
16.526 | 0.415 | tINS | RR | 1 | R72C116[0][B] | g_sound.u_vibrato_lfo/n651_s15/F
16.821 | 0.295 | tNET | RR | 1 | R71C116[3][A] | g_sound.u_vibrato_lfo/n651_s11/I3
17.290 | 0.469 | tINS | RR | 1 | R71C116[3][A] | g_sound.u_vibrato_lfo/n651_s11/F
17.657 | 0.367 | tNET | RR | 1 | R71C119[3][B] | g_sound.u_vibrato_lfo/n651_s7/I3
18.105 | 0.448 | tINS | RR | 4 | R71C119[3][B] | g_sound.u_vibrato_lfo/n651_s7/F
18.820 | 0.715 | tNET | RR | 1 | R72C115[1][B] | g_sound.u_vibrato_lfo/n651_s2/I0
19.294 | 0.474 | tINS | RR | 19 | R72C115[1][B] | g_sound.u_vibrato_lfo/n651_s2/F
20.579 | 1.285 | tNET | RR | 1 | R71C121[0][B] | g_sound.u_vibrato_lfo/n652_s0/I3
20.994 | 0.415 | tINS | RR | 1 | R71C121[0][B] | g_sound.u_vibrato_lfo/n652_s0/F
20.994 | 0.000 | tNET | RR | 1 | R71C121[0][B] | g_sound.u_vibrato_lfo/rate_inc_q_9_s0/D

Data Required Path:

AT | DELAY | TYPE | RF | FANOUT | LOC | NODE
17.800 | 17.800 | | | | | active clock edge time
17.800 | 0.000 | | | | | clk_sys
17.800 | 0.000 | tCL | RR | 1 | IOB117[B] | clk_ibuf/I
19.088 | 1.288 | tINS | RR | 17287 | IOB117[B] | clk_ibuf/O
21.942 | 2.854 | tNET | RR | 1 | R71C121[0][B] | g_sound.u_vibrato_lfo/rate_inc_q_9_s0/CLK
21.885 | -0.057 | tSu | | 1 | R71C121[0][B] | g_sound.u_vibrato_lfo/rate_inc_q_9_s0

Path Statistics:

Clock Skew | 0.000
Setup Relationship | 17.800
Logic Level | 16
Arrival Clock Path Delay | cell: 1.288, 31.105%; route: 2.854, 68.895%
Arrival Data Path Delay | cell: 8.897, 52.795%; route: 7.611, 45.162%; tC2Q: 0.344, 2.043%
Required Clock Path Delay | cell: 1.288, 31.105%; route: 2.854, 68.895%

### Path20

Path Summary:

Slack | 0.900
Data Arrival Time | 17.789
Data Required Time | 18.688
From | g_sound.u_adc_farm/u_scan0/sample_channel_0_s0
To | g_sound.u_calib0/n909_s
Launch Clk | clk_sys:[R]
Latch Clk | clk_sys:[R]

Data Arrival Path:

AT | DELAY | TYPE | RF | FANOUT | LOC | NODE
0.000 | 0.000 | | | | | active clock edge time
0.000 | 0.000 | | | | | clk_sys
0.000 | 0.000 | tCL | RR | 1 | IOB117[B] | clk_ibuf/I
1.288 | 1.288 | tINS | RR | 17287 | IOB117[B] | clk_ibuf/O
4.150 | 2.862 | tNET | RR | 1 | R62C108[0][B] | g_sound.u_adc_farm/u_scan0/sample_channel_0_s0/CLK
4.495 | 0.344 | tC2Q | RR | 147 | R62C108[0][B] | g_sound.u_adc_farm/u_scan0/sample_channel_0_s0/Q
7.030 | 2.536 | tNET | RR | 1 | R64C56[0][A] | g_sound.u_calib0/n4_s16/I2
7.504 | 0.474 | tINS | RR | 1 | R64C56[0][A] | g_sound.u_calib0/n4_s16/F
7.504 | 0.000 | tNET | RR | 1 | R64C56[0][A] | g_sound.u_calib0/n4_s13/I0
7.627 | 0.123 | tINS | RR | 1 | R64C56[0][A] | g_sound.u_calib0/n4_s13/O
7.627 | 0.000 | tNET | RR | 1 | R64C56[0][B] | g_sound.u_calib0/n4_s11/I1
7.704 | 0.078 | tINS | RR | 51 | R64C56[0][B] | g_sound.u_calib0/n4_s11/O
9.299 | 1.595 | tNET | RR | 1 | R61C50[3][B] | g_sound.u_calib0/zero_rd_8_s2/I0
9.769 | 0.469 | tINS | RR | 5 | R61C50[3][B] | g_sound.u_calib0/zero_rd_8_s2/F
10.694 | 0.926 | tNET | RR | 1 | R58C56[0][B] | g_sound.u_calib0/dclamp_9_s11/I3
11.159 | 0.465 | tINS | RR | 1 | R58C56[0][B] | g_sound.u_calib0/dclamp_9_s11/F
11.283 | 0.124 | tNET | RR | 1 | R58C56[3][B] | g_sound.u_calib0/dclamp_9_s5/I1
11.731 | 0.448 | tINS | RR | 2 | R58C56[3][B] | g_sound.u_calib0/dclamp_9_s5/F
11.857 | 0.126 | tNET | RR | 1 | R58C56[3][A] | g_sound.u_calib0/dclamp_9_s3/I0
12.326 | 0.469 | tINS | RR | 18 | R58C56[3][A] | g_sound.u_calib0/dclamp_9_s3/F
14.162 | 1.836 | tNET | RR | 1 | R55C53[1][A] | g_sound.u_calib0/dclamp_8_s1/I1
14.626 | 0.465 | tINS | RR | 3 | R55C53[1][A] | g_sound.u_calib0/dclamp_8_s1/F
14.773 | 0.146 | tNET | RR | 1 | R55C54[0][B] | g_sound.u_calib0/dclamp_8_s11/I1
15.246 | 0.474 | tINS | RR | 1 | R55C54[0][B] | g_sound.u_calib0/dclamp_8_s11/F
15.370 | 0.124 | tNET | RR | 1 | R55C54[1][A] | g_sound.u_calib0/dclamp_8_s6/I3
15.606 | 0.236 | tINS | RR | 5 | R55C54[1][A] | g_sound.u_calib0/dclamp_8_s6/F
15.755 | 0.149 | tNET | RR | 1 | R54C54[1][A] | g_sound.u_calib0/dclamp_8_s33/I1
16.219 | 0.465 | tINS | RR | 3 | R54C54[1][A] | g_sound.u_calib0/dclamp_8_s33/F
16.537 | 0.317 | tNET | RR | 1 | R53C53[1][A] | g_sound.u_calib0/dclamp_3_s0/I3
16.952 | 0.415 | tINS | RR | 1 | R53C53[1][A] | g_sound.u_calib0/dclamp_3_s0/F
17.789 | 0.837 | tNET | RR | 1 | DSP_R47[14] | g_sound.u_calib0/n909_s/A[3]

Data Required Path:

AT | DELAY | TYPE | RF | FANOUT | LOC | NODE
17.800 | 17.800 | | | | | active clock edge time
17.800 | 0.000 | | | | | clk_sys
17.800 | 0.000 | tCL | RR | 1 | IOB117[B] | clk_ibuf/I
19.088 | 1.288 | tINS | RR | 17287 | IOB117[B] | clk_ibuf/O
21.942 | 2.854 | tNET | RR | 1 | DSP_R47[14] | g_sound.u_calib0/n909_s/CLK[0]
18.688 | -3.254 | tSu | | 1 | DSP_R47[14] | g_sound.u_calib0/n909_s

Path Statistics:

Clock Skew | -0.008
Setup Relationship | 17.800
Logic Level | 11
Arrival Clock Path Delay | cell: 1.288, 31.042%; route: 2.862, 68.958%
Arrival Data Path Delay | cell: 4.579, 33.573%; route: 8.715, 63.903%; tC2Q: 0.344, 2.524%
Required Clock Path Delay | cell: 1.288, 31.105%; route: 2.854, 68.895%

### Path21

Path Summary:

Slack | 0.918
Data Arrival Time | 20.744
Data Required Time | 21.662
From | g_sound.u_note_manager/scan_cnt_4_s0
To | g_sound.u_note_manager/best_env_1_s0
Launch Clk | clk_sys:[R]
Latch Clk | clk_sys:[R]

Data Arrival Path:

AT | DELAY | TYPE | RF | FANOUT | LOC | NODE
0.000 | 0.000 | | | | | active clock edge time
0.000 | 0.000 | | | | | clk_sys
0.000 | 0.000 | tCL | RR | 1 | IOB117[B] | clk_ibuf/I
1.288 | 1.288 | tINS | RR | 17287 | IOB117[B] | clk_ibuf/O
4.587 | 3.299 | tNET | RR | 1 | R37C62[0][A] | g_sound.u_note_manager/scan_cnt_4_s0/CLK
4.932 | 0.344 | tC2Q | RR | 53 | R37C62[0][A] | g_sound.u_note_manager/scan_cnt_4_s0/Q
5.550 | 0.619 | tNET | RR | 1 | R35C60[0][A] | g_sound.u_note_manager/state_2_s7/I1
6.015 | 0.465 | tINS | RR | 22 | R35C60[0][A] | g_sound.u_note_manager/state_2_s7/F
8.983 | 2.968 | tNET | RR | 1 | R60C72[3][A] | g_sound.u_note_manager/cand_env_11_s59/I0
9.452 | 0.469 | tINS | RR | 10 | R60C72[3][A] | g_sound.u_note_manager/cand_env_11_s59/F
12.079 | 2.627 | tNET | RR | 1 | R35C64[1][A] | g_sound.u_note_manager/cand_env_6_s42/I3
12.543 | 0.465 | tINS | RR | 1 | R35C64[1][A] | g_sound.u_note_manager/cand_env_6_s42/F
12.546 | 0.002 | tNET | RR | 1 | R35C64[0][B] | g_sound.u_note_manager/cand_env_6_s35/I1
12.782 | 0.236 | tINS | RR | 2 | R35C64[0][B] | g_sound.u_note_manager/cand_env_6_s35/F
12.786 | 0.005 | tNET | RR | 1 | R35C64[3][B] | g_sound.u_note_manager/n26709_s59/I2
13.256 | 0.469 | tINS | RR | 1 | R35C64[3][B] | g_sound.u_note_manager/n26709_s59/F
13.622 | 0.367 | tNET | RR | 1 | R36C66[2][B] | g_sound.u_note_manager/n26709_s50/I2
14.087 | 0.465 | tINS | RR | 3 | R36C66[2][B] | g_sound.u_note_manager/n26709_s50/F
15.810 | 1.723 | tNET | RR | 1 | R58C75[1][A] | g_sound.u_note_manager/n26709_s35/I0
16.226 | 0.415 | tINS | RR | 1 | R58C75[1][A] | g_sound.u_note_manager/n26709_s35/F
16.349 | 0.124 | tNET | RR | 1 | R58C75[3][B] | g_sound.u_note_manager/n26709_s21/I2
16.818 | 0.469 | tINS | RR | 1 | R58C75[3][B] | g_sound.u_note_manager/n26709_s21/F
16.821 | 0.002 | tNET | RR | 1 | R58C75[3][A] | g_sound.u_note_manager/n26709_s10/I0
17.268 | 0.448 | tINS | RR | 2 | R58C75[3][A] | g_sound.u_note_manager/n26709_s10/F
17.979 | 0.711 | tNET | RR | 1 | R55C76[3][B] | g_sound.u_note_manager/n26709_s6/I0
18.353 | 0.373 | tINS | RR | 1 | R55C76[3][B] | g_sound.u_note_manager/n26709_s6/F
18.666 | 0.313 | tNET | RR | 1 | R54C75[1][A] | g_sound.u_note_manager/n26709_s5/I0
19.139 | 0.474 | tINS | RR | 40 | R54C75[1][A] | g_sound.u_note_manager/n26709_s5/F
20.744 | 1.604 | tNET | RR | 1 | R45C62[1][B] | g_sound.u_note_manager/best_env_1_s0/CE

Data Required Path:

AT | DELAY | TYPE | RF | FANOUT | LOC | NODE
17.800 | 17.800 | | | | | active clock edge time
17.800 | 0.000 | | | | | clk_sys
17.800 | 0.000 | tCL | RR | 1 | IOB117[B] | clk_ibuf/I
19.088 | 1.288 | tINS | RR | 17287 | IOB117[B] | clk_ibuf/O
21.942 | 2.854 | tNET | RR | 1 | R45C62[1][B] | g_sound.u_note_manager/best_env_1_s0/CLK
21.662 | -0.280 | tSu | | 1 | R45C62[1][B] | g_sound.u_note_manager/best_env_1_s0

Path Statistics:

Clock Skew | -0.446
Setup Relationship | 17.800
Logic Level | 12
Arrival Clock Path Delay | cell: 1.288, 28.084%; route: 3.299, 71.916%
Arrival Data Path Delay | cell: 4.748, 29.385%; route: 11.064, 68.484%; tC2Q: 0.344, 2.131%
Required Clock Path Delay | cell: 1.288, 31.105%; route: 2.854, 68.895%

### Path22

Path Summary:

Slack | 0.918
Data Arrival Time | 20.744
Data Required Time | 21.662
From | g_sound.u_note_manager/scan_cnt_4_s0
To | g_sound.u_note_manager/best_env_2_s0
Launch Clk | clk_sys:[R]
Latch Clk | clk_sys:[R]

Data Arrival Path:

AT | DELAY | TYPE | RF | FANOUT | LOC | NODE
0.000 | 0.000 | | | | | active clock edge time
0.000 | 0.000 | | | | | clk_sys
0.000 | 0.000 | tCL | RR | 1 | IOB117[B] | clk_ibuf/I
1.288 | 1.288 | tINS | RR | 17287 | IOB117[B] | clk_ibuf/O
4.587 | 3.299 | tNET | RR | 1 | R37C62[0][A] | g_sound.u_note_manager/scan_cnt_4_s0/CLK
4.932 | 0.344 | tC2Q | RR | 53 | R37C62[0][A] | g_sound.u_note_manager/scan_cnt_4_s0/Q
5.550 | 0.619 | tNET | RR | 1 | R35C60[0][A] | g_sound.u_note_manager/state_2_s7/I1
6.015 | 0.465 | tINS | RR | 22 | R35C60[0][A] | g_sound.u_note_manager/state_2_s7/F
8.983 | 2.968 | tNET | RR | 1 | R60C72[3][A] | g_sound.u_note_manager/cand_env_11_s59/I0
9.452 | 0.469 | tINS | RR | 10 | R60C72[3][A] | g_sound.u_note_manager/cand_env_11_s59/F
12.079 | 2.627 | tNET | RR | 1 | R35C64[1][A] | g_sound.u_note_manager/cand_env_6_s42/I3
12.543 | 0.465 | tINS | RR | 1 | R35C64[1][A] | g_sound.u_note_manager/cand_env_6_s42/F
12.546 | 0.002 | tNET | RR | 1 | R35C64[0][B] | g_sound.u_note_manager/cand_env_6_s35/I1
12.782 | 0.236 | tINS | RR | 2 | R35C64[0][B] | g_sound.u_note_manager/cand_env_6_s35/F
12.786 | 0.005 | tNET | RR | 1 | R35C64[3][B] | g_sound.u_note_manager/n26709_s59/I2
13.256 | 0.469 | tINS | RR | 1 | R35C64[3][B] | g_sound.u_note_manager/n26709_s59/F
13.622 | 0.367 | tNET | RR | 1 | R36C66[2][B] | g_sound.u_note_manager/n26709_s50/I2
14.087 | 0.465 | tINS | RR | 3 | R36C66[2][B] | g_sound.u_note_manager/n26709_s50/F
15.810 | 1.723 | tNET | RR | 1 | R58C75[1][A] | g_sound.u_note_manager/n26709_s35/I0
16.226 | 0.415 | tINS | RR | 1 | R58C75[1][A] | g_sound.u_note_manager/n26709_s35/F
16.349 | 0.124 | tNET | RR | 1 | R58C75[3][B] | g_sound.u_note_manager/n26709_s21/I2
16.818 | 0.469 | tINS | RR | 1 | R58C75[3][B] | g_sound.u_note_manager/n26709_s21/F
16.821 | 0.002 | tNET | RR | 1 | R58C75[3][A] | g_sound.u_note_manager/n26709_s10/I0
17.268 | 0.448 | tINS | RR | 2 | R58C75[3][A] | g_sound.u_note_manager/n26709_s10/F
17.979 | 0.711 | tNET | RR | 1 | R55C76[3][B] | g_sound.u_note_manager/n26709_s6/I0
18.353 | 0.373 | tINS | RR | 1 | R55C76[3][B] | g_sound.u_note_manager/n26709_s6/F
18.666 | 0.313 | tNET | RR | 1 | R54C75[1][A] | g_sound.u_note_manager/n26709_s5/I0
19.139 | 0.474 | tINS | RR | 40 | R54C75[1][A] | g_sound.u_note_manager/n26709_s5/F
20.744 | 1.604 | tNET | RR | 1 | R45C62[0][A] | g_sound.u_note_manager/best_env_2_s0/CE

Data Required Path:

AT | DELAY | TYPE | RF | FANOUT | LOC | NODE
17.800 | 17.800 | | | | | active clock edge time
17.800 | 0.000 | | | | | clk_sys
17.800 | 0.000 | tCL | RR | 1 | IOB117[B] | clk_ibuf/I
19.088 | 1.288 | tINS | RR | 17287 | IOB117[B] | clk_ibuf/O
21.942 | 2.854 | tNET | RR | 1 | R45C62[0][A] | g_sound.u_note_manager/best_env_2_s0/CLK
21.662 | -0.280 | tSu | | 1 | R45C62[0][A] | g_sound.u_note_manager/best_env_2_s0

Path Statistics:

Clock Skew | -0.446
Setup Relationship | 17.800
Logic Level | 12
Arrival Clock Path Delay | cell: 1.288, 28.084%; route: 3.299, 71.916%
Arrival Data Path Delay | cell: 4.748, 29.385%; route: 11.064, 68.484%; tC2Q: 0.344, 2.131%
Required Clock Path Delay | cell: 1.288, 31.105%; route: 2.854, 68.895%

### Path23

Path Summary:

Slack | 0.972
Data Arrival Time | 20.921
Data Required Time | 21.893
From | g_sound.u_fader_gear/gear_o_0_s0
To | g_sound.u_vibrato_lfo/rate_inc_q_19_s0
Launch Clk | clk_sys:[R]
Latch Clk | clk_sys:[R]

Data Arrival Path:

AT | DELAY | TYPE | RF | FANOUT | LOC | NODE
0.000 | 0.000 | | | | | active clock edge time
0.000 | 0.000 | | | | | clk_sys
0.000 | 0.000 | tCL | RR | 1 | IOB117[B] | clk_ibuf/I
1.288 | 1.288 | tINS | RR | 17287 | IOB117[B] | clk_ibuf/O
4.142 | 2.854 | tNET | RR | 1 | R60C109[0][A] | g_sound.u_fader_gear/gear_o_0_s0/CLK
4.486 | 0.344 | tC2Q | RR | 23 | R60C109[0][A] | g_sound.u_fader_gear/gear_o_0_s0/Q
6.011 | 1.524 | tNET | RR | 1 | R66C119[3][B] | g_sound.u_fader_gear/g_sound.vib_rate_sel_0_s/I0
6.458 | 0.448 | tINS | RR | 1 | R66C119[3][B] | g_sound.u_fader_gear/g_sound.vib_rate_sel_0_s/F
7.519 | 1.061 | tNET | RR | 97 | DSP_R65[31] | g_sound.u_vibrato_lfo/rate_product_0_s/A[0]
10.176 | 2.657 | tINS | RR | 3 | DSP_R65[31] | g_sound.u_vibrato_lfo/rate_product_0_s/DOUT[15]
11.142 | 0.966 | tNET | RR | 1 | R68C116[0][A] | g_sound.u_vibrato_lfo/rate_target_w_5_s3/I2
11.607 | 0.465 | tINS | RR | 3 | R68C116[0][A] | g_sound.u_vibrato_lfo/rate_target_w_5_s3/F
11.753 | 0.146 | tNET | RR | 1 | R69C116[2][B] | g_sound.u_vibrato_lfo/rate_target_w_8_s3/I0
12.218 | 0.465 | tINS | RR | 4 | R69C116[2][B] | g_sound.u_vibrato_lfo/rate_target_w_8_s3/F
12.537 | 0.319 | tNET | RR | 1 | R68C117[2][A] | g_sound.u_vibrato_lfo/rate_target_w_9_s2/I1
13.002 | 0.465 | tINS | RR | 8 | R68C117[2][A] | g_sound.u_vibrato_lfo/rate_target_w_9_s2/F
13.614 | 0.612 | tNET | RR | 2 | R71C116[1][B] | g_sound.u_vibrato_lfo/n462_s/I0
14.114 | 0.501 | tINS | RF | 1 | R71C116[1][B] | g_sound.u_vibrato_lfo/n462_s/COUT
14.114 | 0.000 | tNET | FF | 2 | R71C116[2][A] | g_sound.u_vibrato_lfo/n461_s/CIN
14.159 | 0.045 | tINS | FR | 1 | R71C116[2][A] | g_sound.u_vibrato_lfo/n461_s/COUT
14.159 | 0.000 | tNET | RR | 2 | R71C116[2][B] | g_sound.u_vibrato_lfo/n460_s/CIN
14.204 | 0.045 | tINS | RR | 1 | R71C116[2][B] | g_sound.u_vibrato_lfo/n460_s/COUT
14.204 | 0.000 | tNET | RR | 2 | R71C117[0][A] | g_sound.u_vibrato_lfo/n459_s/CIN
14.249 | 0.045 | tINS | RR | 1 | R71C117[0][A] | g_sound.u_vibrato_lfo/n459_s/COUT
14.249 | 0.000 | tNET | RR | 2 | R71C117[0][B] | g_sound.u_vibrato_lfo/n458_s/CIN
14.294 | 0.045 | tINS | RR | 1 | R71C117[0][B] | g_sound.u_vibrato_lfo/n458_s/COUT
14.294 | 0.000 | tNET | RR | 2 | R71C117[1][A] | g_sound.u_vibrato_lfo/n457_s/CIN
14.339 | 0.045 | tINS | RR | 1 | R71C117[1][A] | g_sound.u_vibrato_lfo/n457_s/COUT
14.339 | 0.000 | tNET | RR | 2 | R71C117[1][B] | g_sound.u_vibrato_lfo/n456_s/CIN
14.384 | 0.045 | tINS | RR | 1 | R71C117[1][B] | g_sound.u_vibrato_lfo/n456_s/COUT
14.384 | 0.000 | tNET | RR | 2 | R71C117[2][A] | g_sound.u_vibrato_lfo/n455_s/CIN
14.429 | 0.045 | tINS | RR | 1 | R71C117[2][A] | g_sound.u_vibrato_lfo/n455_s/COUT
14.429 | 0.000 | tNET | RR | 2 | R71C117[2][B] | g_sound.u_vibrato_lfo/n454_s/CIN
14.474 | 0.045 | tINS | RR | 1 | R71C117[2][B] | g_sound.u_vibrato_lfo/n454_s/COUT
14.474 | 0.000 | tNET | RR | 2 | R71C118[0][A] | g_sound.u_vibrato_lfo/n453_s/CIN
14.519 | 0.045 | tINS | RR | 1 | R71C118[0][A] | g_sound.u_vibrato_lfo/n453_s/COUT
14.519 | 0.000 | tNET | RR | 2 | R71C118[0][B] | g_sound.u_vibrato_lfo/n452_s/CIN
14.564 | 0.045 | tINS | RR | 1 | R71C118[0][B] | g_sound.u_vibrato_lfo/n452_s/COUT
14.564 | 0.000 | tNET | RR | 2 | R71C118[1][A] | g_sound.u_vibrato_lfo/n451_s/CIN
14.609 | 0.045 | tINS | RR | 1 | R71C118[1][A] | g_sound.u_vibrato_lfo/n451_s/COUT
14.609 | 0.000 | tNET | RR | 2 | R71C118[1][B] | g_sound.u_vibrato_lfo/n450_s/CIN
14.654 | 0.045 | tINS | RR | 1 | R71C118[1][B] | g_sound.u_vibrato_lfo/n450_s/COUT
14.654 | 0.000 | tNET | RR | 2 | R71C118[2][A] | g_sound.u_vibrato_lfo/n449_s/CIN
14.699 | 0.045 | tINS | RR | 1 | R71C118[2][A] | g_sound.u_vibrato_lfo/n449_s/COUT
14.699 | 0.000 | tNET | RR | 2 | R71C118[2][B] | g_sound.u_vibrato_lfo/n448_s/CIN
14.970 | 0.271 | tINS | RF | 1 | R71C118[2][B] | g_sound.u_vibrato_lfo/n448_s/SUM
14.975 | 0.005 | tNET | FF | 1 | R71C118[3][A] | g_sound.u_vibrato_lfo/n651_s19/I1
15.423 | 0.448 | tINS | FR | 1 | R71C118[3][A] | g_sound.u_vibrato_lfo/n651_s19/F
15.425 | 0.002 | tNET | RR | 1 | R71C118[3][B] | g_sound.u_vibrato_lfo/n651_s18/I3
15.798 | 0.373 | tINS | RR | 1 | R71C118[3][B] | g_sound.u_vibrato_lfo/n651_s18/F
16.111 | 0.313 | tNET | RR | 1 | R72C116[0][B] | g_sound.u_vibrato_lfo/n651_s15/I3
16.526 | 0.415 | tINS | RR | 1 | R72C116[0][B] | g_sound.u_vibrato_lfo/n651_s15/F
16.821 | 0.295 | tNET | RR | 1 | R71C116[3][A] | g_sound.u_vibrato_lfo/n651_s11/I3
17.290 | 0.469 | tINS | RR | 1 | R71C116[3][A] | g_sound.u_vibrato_lfo/n651_s11/F
17.657 | 0.367 | tNET | RR | 1 | R71C119[3][B] | g_sound.u_vibrato_lfo/n651_s7/I3
18.105 | 0.448 | tINS | RR | 4 | R71C119[3][B] | g_sound.u_vibrato_lfo/n651_s7/F
18.820 | 0.715 | tNET | RR | 1 | R72C115[1][B] | g_sound.u_vibrato_lfo/n651_s2/I0
19.294 | 0.474 | tINS | RR | 19 | R72C115[1][B] | g_sound.u_vibrato_lfo/n651_s2/F
20.684 | 1.390 | tNET | RR | 1 | R71C120[1][B] | g_sound.u_vibrato_lfo/n674_s0/I0
20.921 | 0.236 | tINS | RR | 1 | R71C120[1][B] | g_sound.u_vibrato_lfo/n674_s0/F
20.921 | 0.000 | tNET | RR | 1 | R71C120[1][B] | g_sound.u_vibrato_lfo/rate_inc_q_19_s0/D

Data Required Path:

AT | DELAY | TYPE | RF | FANOUT | LOC | NODE
17.800 | 17.800 | | | | | active clock edge time
17.800 | 0.000 | | | | | clk_sys
17.800 | 0.000 | tCL | RR | 1 | IOB117[B] | clk_ibuf/I
19.088 | 1.288 | tINS | RR | 17287 | IOB117[B] | clk_ibuf/O
21.950 | 2.862 | tNET | RR | 1 | R71C120[1][B] | g_sound.u_vibrato_lfo/rate_inc_q_19_s0/CLK
21.893 | -0.057 | tSu | | 1 | R71C120[1][B] | g_sound.u_vibrato_lfo/rate_inc_q_19_s0

Path Statistics:

Clock Skew | 0.008
Setup Relationship | 17.800
Logic Level | 16
Arrival Clock Path Delay | cell: 1.288, 31.105%; route: 2.854, 68.895%
Arrival Data Path Delay | cell: 8.718, 51.959%; route: 7.716, 45.989%; tC2Q: 0.344, 2.052%
Required Clock Path Delay | cell: 1.288, 31.042%; route: 2.862, 68.958%

### Path24

Path Summary:

Slack | 1.085
Data Arrival Time | 17.551
Data Required Time | 18.637
From | g_sound.u_adc_farm/u_scan0/sample_channel_0_s0
To | g_sound.u_calib0/n909_s
Launch Clk | clk_sys:[R]
Latch Clk | clk_sys:[R]

Data Arrival Path:

AT | DELAY | TYPE | RF | FANOUT | LOC | NODE
0.000 | 0.000 | | | | | active clock edge time
0.000 | 0.000 | | | | | clk_sys
0.000 | 0.000 | tCL | RR | 1 | IOB117[B] | clk_ibuf/I
1.288 | 1.288 | tINS | RR | 17287 | IOB117[B] | clk_ibuf/O
4.150 | 2.862 | tNET | RR | 1 | R62C108[0][B] | g_sound.u_adc_farm/u_scan0/sample_channel_0_s0/CLK
4.495 | 0.344 | tC2Q | RR | 147 | R62C108[0][B] | g_sound.u_adc_farm/u_scan0/sample_channel_0_s0/Q
7.030 | 2.536 | tNET | RR | 1 | R64C56[0][A] | g_sound.u_calib0/n4_s16/I2
7.504 | 0.474 | tINS | RR | 1 | R64C56[0][A] | g_sound.u_calib0/n4_s16/F
7.504 | 0.000 | tNET | RR | 1 | R64C56[0][A] | g_sound.u_calib0/n4_s13/I0
7.627 | 0.123 | tINS | RR | 1 | R64C56[0][A] | g_sound.u_calib0/n4_s13/O
7.627 | 0.000 | tNET | RR | 1 | R64C56[0][B] | g_sound.u_calib0/n4_s11/I1
7.704 | 0.078 | tINS | RR | 51 | R64C56[0][B] | g_sound.u_calib0/n4_s11/O
9.299 | 1.595 | tNET | RR | 1 | R61C50[3][B] | g_sound.u_calib0/zero_rd_8_s2/I0
9.769 | 0.469 | tINS | RR | 5 | R61C50[3][B] | g_sound.u_calib0/zero_rd_8_s2/F
10.694 | 0.926 | tNET | RR | 1 | R58C56[0][B] | g_sound.u_calib0/dclamp_9_s11/I3
11.159 | 0.465 | tINS | RR | 1 | R58C56[0][B] | g_sound.u_calib0/dclamp_9_s11/F
11.283 | 0.124 | tNET | RR | 1 | R58C56[3][B] | g_sound.u_calib0/dclamp_9_s5/I1
11.731 | 0.448 | tINS | RR | 2 | R58C56[3][B] | g_sound.u_calib0/dclamp_9_s5/F
11.857 | 0.126 | tNET | RR | 1 | R58C56[3][A] | g_sound.u_calib0/dclamp_9_s3/I0
12.326 | 0.469 | tINS | RR | 18 | R58C56[3][A] | g_sound.u_calib0/dclamp_9_s3/F
14.162 | 1.836 | tNET | RR | 1 | R55C53[1][A] | g_sound.u_calib0/dclamp_8_s1/I1
14.626 | 0.465 | tINS | RR | 3 | R55C53[1][A] | g_sound.u_calib0/dclamp_8_s1/F
14.773 | 0.146 | tNET | RR | 1 | R55C54[0][B] | g_sound.u_calib0/dclamp_8_s11/I1
15.246 | 0.474 | tINS | RR | 1 | R55C54[0][B] | g_sound.u_calib0/dclamp_8_s11/F
15.370 | 0.124 | tNET | RR | 1 | R55C54[1][A] | g_sound.u_calib0/dclamp_8_s6/I3
15.606 | 0.236 | tINS | RR | 5 | R55C54[1][A] | g_sound.u_calib0/dclamp_8_s6/F
15.755 | 0.149 | tNET | RR | 1 | R54C54[1][A] | g_sound.u_calib0/dclamp_8_s33/I1
16.219 | 0.465 | tINS | RR | 3 | R54C54[1][A] | g_sound.u_calib0/dclamp_8_s33/F
16.537 | 0.317 | tNET | RR | 1 | R52C53[3][B] | g_sound.u_calib0/dclamp_4_s0/I2
16.798 | 0.261 | tINS | RF | 1 | R52C53[3][B] | g_sound.u_calib0/dclamp_4_s0/F
17.551 | 0.754 | tNET | FF | 1 | DSP_R47[14] | g_sound.u_calib0/n909_s/A[4]

Data Required Path:

AT | DELAY | TYPE | RF | FANOUT | LOC | NODE
17.800 | 17.800 | | | | | active clock edge time
17.800 | 0.000 | | | | | clk_sys
17.800 | 0.000 | tCL | RR | 1 | IOB117[B] | clk_ibuf/I
19.088 | 1.288 | tINS | RR | 17287 | IOB117[B] | clk_ibuf/O
21.942 | 2.854 | tNET | RR | 1 | DSP_R47[14] | g_sound.u_calib0/n909_s/CLK[0]
18.637 | -3.305 | tSu | | 1 | DSP_R47[14] | g_sound.u_calib0/n909_s

Path Statistics:

Clock Skew | -0.008
Setup Relationship | 17.800
Logic Level | 11
Arrival Clock Path Delay | cell: 1.288, 31.042%; route: 2.862, 68.958%
Arrival Data Path Delay | cell: 4.425, 33.017%; route: 8.632, 64.414%; tC2Q: 0.344, 2.569%
Required Clock Path Delay | cell: 1.288, 31.105%; route: 2.854, 68.895%

### Path25

Path Summary:

Slack | 1.087
Data Arrival Time | 17.742
Data Required Time | 18.829
From | g_sound.u_calib_span/cur_axis_o_3_s1
To | g_sound.u_calib1/n909_s
Launch Clk | clk_sys:[R]
Latch Clk | clk_sys:[R]

Data Arrival Path:

AT | DELAY | TYPE | RF | FANOUT | LOC | NODE
0.000 | 0.000 | | | | | active clock edge time
0.000 | 0.000 | | | | | clk_sys
0.000 | 0.000 | tCL | RR | 1 | IOB117[B] | clk_ibuf/I
1.288 | 1.288 | tINS | RR | 17287 | IOB117[B] | clk_ibuf/O
4.142 | 2.854 | tNET | RR | 1 | R58C113[0][B] | g_sound.u_calib_span/cur_axis_o_3_s1/CLK
4.473 | 0.331 | tC2Q | RF | 74 | R58C113[0][B] | g_sound.u_calib_span/cur_axis_o_3_s1/Q
6.570 | 2.097 | tNET | FF | 1 | R58C104[0][A] | n4583_s1/I2
7.034 | 0.465 | tINS | FR | 13 | R58C104[0][A] | n4583_s1/F
10.921 | 3.887 | tNET | RR | 1 | R70C43[3][A] | g_sound.u_calib1/dclamp_7_s26/I2
11.182 | 0.261 | tINS | RF | 1 | R70C43[3][A] | g_sound.u_calib1/dclamp_7_s26/F
11.310 | 0.128 | tNET | FF | 1 | R69C43[3][A] | g_sound.u_calib1/dclamp_7_s18/I3
11.684 | 0.373 | tINS | FR | 1 | R69C43[3][A] | g_sound.u_calib1/dclamp_7_s18/F
11.826 | 0.142 | tNET | RR | 1 | R68C43[2][B] | g_sound.u_calib1/dclamp_7_s16/I3
12.299 | 0.474 | tINS | RR | 1 | R68C43[2][B] | g_sound.u_calib1/dclamp_7_s16/F
12.302 | 0.002 | tNET | RR | 1 | R68C43[3][B] | g_sound.u_calib1/dclamp_7_s21/I0
12.749 | 0.448 | tINS | RR | 1 | R68C43[3][B] | g_sound.u_calib1/dclamp_7_s21/F
12.891 | 0.142 | tNET | RR | 1 | R68C44[1][B] | g_sound.u_calib1/dclamp_7_s10/I1
13.306 | 0.415 | tINS | RR | 2 | R68C44[1][B] | g_sound.u_calib1/dclamp_7_s10/F
13.311 | 0.005 | tNET | RR | 1 | R68C44[1][A] | g_sound.u_calib1/dclamp_7_s6/I0
13.775 | 0.465 | tINS | RR | 2 | R68C44[1][A] | g_sound.u_calib1/dclamp_7_s6/F
14.212 | 0.436 | tNET | RR | 1 | R70C43[2][B] | g_sound.u_calib1/dclamp_7_s4/I1
14.676 | 0.465 | tINS | RR | 3 | R70C43[2][B] | g_sound.u_calib1/dclamp_7_s4/F
14.823 | 0.146 | tNET | RR | 1 | R70C42[2][B] | g_sound.u_calib1/dclamp_8_s9/I3
15.296 | 0.474 | tINS | RR | 1 | R70C42[2][B] | g_sound.u_calib1/dclamp_8_s9/F
15.438 | 0.142 | tNET | RR | 1 | R70C43[0][A] | g_sound.u_calib1/dclamp_8_s7/I1
15.853 | 0.415 | tINS | RR | 2 | R70C43[0][A] | g_sound.u_calib1/dclamp_8_s7/F
16.168 | 0.315 | tNET | RR | 1 | R71C44[0][B] | g_sound.u_calib1/dclamp_8_s3/I2
16.633 | 0.465 | tINS | RR | 9 | R71C44[0][B] | g_sound.u_calib1/dclamp_8_s3/F
16.789 | 0.156 | tNET | RR | 1 | R70C44[0][B] | g_sound.u_calib1/dclamp_8_s0/I2
17.204 | 0.415 | tINS | RR | 1 | R70C44[0][B] | g_sound.u_calib1/dclamp_8_s0/F
17.742 | 0.538 | tNET | RR | 1 | DSP_R65[13] | g_sound.u_calib1/n909_s/A[8]

Data Required Path:

AT | DELAY | TYPE | RF | FANOUT | LOC | NODE
17.800 | 17.800 | | | | | active clock edge time
17.800 | 0.000 | | | | | clk_sys
17.800 | 0.000 | tCL | RR | 1 | IOB117[B] | clk_ibuf/I
19.088 | 1.288 | tINS | RR | 17287 | IOB117[B] | clk_ibuf/O
21.942 | 2.854 | tNET | RR | 1 | DSP_R65[13] | g_sound.u_calib1/n909_s/CLK[0]
18.829 | -3.112 | tSu | | 1 | DSP_R65[13] | g_sound.u_calib1/n909_s

Path Statistics:

Clock Skew | 0.000
Setup Relationship | 17.800
Logic Level | 13
Arrival Clock Path Delay | cell: 1.288, 31.105%; route: 2.854, 68.895%
Arrival Data Path Delay | cell: 5.133, 37.745%; route: 8.136, 59.823%; tC2Q: 0.331, 2.432%
Required Clock Path Delay | cell: 1.288, 31.105%; route: 2.854, 68.895%

### Hold Analysis Report

#### Report Command:report_timing -hold -max_paths 25 -max_common_paths 1

### Path1

Path Summary:

Slack | 0.115
Data Arrival Time | 3.179
Data Required Time | 3.064
From | u_rst_sync/sync_chain_1_s0
To | u_hdmi/rstn_ser_0_s0
Launch Clk | clk_sys:[R]
Latch Clk | serial_clk:[R]

Data Arrival Path:

AT | DELAY | TYPE | RF | FANOUT | LOC | NODE
0.000 | 0.000 | | | | | active clock edge time
0.000 | 0.000 | | | | | clk_sys
0.000 | 0.000 | tCL | RR | 1 | IOB117[B] | clk_ibuf/I
0.952 | 0.952 | tINS | RR | 17287 | IOB117[B] | clk_ibuf/O
2.193 | 1.241 | tNET | RR | 1 | R73C55[1][A] | u_rst_sync/sync_chain_1_s0/CLK
2.323 | 0.130 | tC2Q | RR | 11918 | R73C55[1][A] | u_rst_sync/sync_chain_1_s0/Q
3.179 | 0.856 | tNET | RR | 1 | R34C146[2][A] | u_hdmi/rstn_ser_0_s0/RESET

Data Required Path:

AT | DELAY | TYPE | RF | FANOUT | LOC | NODE
0.000 | 0.000 | | | | | active clock edge time
0.000 | 0.000 | | | | | serial_clk
2.186 | 2.186 | tCL | RR | 7 | PLL_R[1] | u_hdmi/u_clk/u_pll/CLKOUT0
3.113 | 0.927 | tNET | RR | 1 | R34C146[2][A] | u_hdmi/rstn_ser_0_s0/CLK
3.148 | 0.035 | tUnc
3.064 | -0.085 | tHld | | 1 | R34C146[2][A] | u_hdmi/rstn_ser_0_s0

Path Statistics:

Clock Skew | 0.920
Hold Relationship | 0.000
Logic Level | 1
Arrival Clock Path Delay | cell: 0.952, 43.415%; route: 1.241, 56.585%
Arrival Data Path Delay | cell: 0.000, 0.000%; route: 0.856, 86.849%; tC2Q: 0.130, 13.151%
Required Clock Path Delay | cell: 0.000, 0.000%; route: 0.927, 100.000%

### Path2

Path Summary:

Slack | 0.128
Data Arrival Time | 2.530
Data Required Time | 2.402
From | g_sound.u_looper/rd_ptr_r_9_s0
To | g_sound.u_looper/ep_mem_ep_mem_0_5_s
Launch Clk | clk_sys:[R]
Latch Clk | clk_sys:[R]

Data Arrival Path:

AT | DELAY | TYPE | RF | FANOUT | LOC | NODE
0.000 | 0.000 | | | | | active clock edge time
0.000 | 0.000 | | | | | clk_sys
0.000 | 0.000 | tCL | RR | 1 | IOB117[B] | clk_ibuf/I
0.952 | 0.952 | tINS | RR | 17287 | IOB117[B] | clk_ibuf/O
2.186 | 1.234 | tNET | RR | 1 | R42C37[1][B] | g_sound.u_looper/rd_ptr_r_9_s0/CLK
2.316 | 0.130 | tC2Q | RR | 19 | R42C37[1][B] | g_sound.u_looper/rd_ptr_r_9_s0/Q
2.530 | 0.214 | tNET | RR | 1 | BSRAM_R38[7] | g_sound.u_looper/ep_mem_ep_mem_0_5_s/ADB[12]

Data Required Path:

AT | DELAY | TYPE | RF | FANOUT | LOC | NODE
0.000 | 0.000 | | | | | active clock edge time
0.000 | 0.000 | | | | | clk_sys
0.000 | 0.000 | tCL | RR | 1 | IOB117[B] | clk_ibuf/I
0.952 | 0.952 | tINS | RR | 17287 | IOB117[B] | clk_ibuf/O
2.371 | 1.418 | tNET | RR | 1 | BSRAM_R38[7] | g_sound.u_looper/ep_mem_ep_mem_0_5_s/CLKB
2.402 | 0.032 | tHld | | 1 | BSRAM_R38[7] | g_sound.u_looper/ep_mem_ep_mem_0_5_s

Path Statistics:

Clock Skew | 0.185
Hold Relationship | 0.000
Logic Level | 1
Arrival Clock Path Delay | cell: 0.952, 43.558%; route: 1.234, 56.442%
Arrival Data Path Delay | cell: 0.000, 0.000%; route: 0.214, 62.304%; tC2Q: 0.130, 37.696%
Required Clock Path Delay | cell: 0.952, 40.168%; route: 1.418, 59.832%

### Path3

Path Summary:

Slack | 0.148
Data Arrival Time | 3.011
Data Required Time | 2.863
From | u_hdmi/u_blue/symbol_7_s0
To | u_hdmi/u_serializer/lanes[0].u_oser
Launch Clk | pixel_clk:[R]
Latch Clk | pixel_clk:[R]

Data Arrival Path:

AT | DELAY | TYPE | RF | FANOUT | LOC | NODE
0.000 | 0.000 | | | | | active clock edge time
0.000 | 0.000 | | | | | pixel_clk
2.186 | 2.186 | tCL | RR | 340 | PLL_R[1] | u_hdmi/u_clk/u_pll/CLKOUT1
2.788 | 0.602 | tNET | RR | 1 | R26C146[0][A] | u_hdmi/u_blue/symbol_7_s0/CLK
2.918 | 0.130 | tC2Q | RR | 4 | R26C146[0][A] | u_hdmi/u_blue/symbol_7_s0/Q
3.011 | 0.093 | tNET | RR | 1 | IOR26[A] | u_hdmi/u_serializer/lanes[0].u_oser/D7

Data Required Path:

AT | DELAY | TYPE | RF | FANOUT | LOC | NODE
0.000 | 0.000 | | | | | active clock edge time
0.000 | 0.000 | | | | | pixel_clk
2.186 | 2.186 | tCL | RR | 340 | PLL_R[1] | u_hdmi/u_clk/u_pll/CLKOUT1
2.788 | 0.602 | tNET | RR | 1 | IOR26[A] | u_hdmi/u_serializer/lanes[0].u_oser/PCLK
2.863 | 0.075 | tHld | | 1 | IOR26[A] | u_hdmi/u_serializer/lanes[0].u_oser

Path Statistics:

Clock Skew | 0.000
Hold Relationship | 0.000
Logic Level | 1
Arrival Clock Path Delay | cell: 0.000, 0.000%; route: 0.602, 100.000%
Arrival Data Path Delay | cell: 0.000, 0.000%; route: 0.093, 41.700%; tC2Q: 0.130, 58.300%
Required Clock Path Delay | cell: 0.000, 0.000%; route: 0.602, 100.000%

### Path4

Path Summary:

Slack | 0.198
Data Arrival Time | 2.573
Data Required Time | 2.375
From | g_sound.u_envelope_bank/env_level_o_470_s0
To | g_sound.u_note_manager/env_level_r_470_s0
Launch Clk | clk_sys:[R]
Latch Clk | clk_sys:[R]

Data Arrival Path:

AT | DELAY | TYPE | RF | FANOUT | LOC | NODE
0.000 | 0.000 | | | | | active clock edge time
0.000 | 0.000 | | | | | clk_sys
0.000 | 0.000 | tCL | RR | 1 | IOB117[B] | clk_ibuf/I
0.952 | 0.952 | tINS | RR | 17287 | IOB117[B] | clk_ibuf/O
2.186 | 1.234 | tNET | RR | 1 | R43C65[3][A] | g_sound.u_envelope_bank/env_level_o_470_s0/CLK
2.316 | 0.130 | tC2Q | RR | 1 | R43C65[3][A] | g_sound.u_envelope_bank/env_level_o_470_s0/Q
2.573 | 0.257 | tNET | RR | 1 | R35C65[0][A] | g_sound.u_note_manager/env_level_r_470_s0/D

Data Required Path:

AT | DELAY | TYPE | RF | FANOUT | LOC | NODE
0.000 | 0.000 | | | | | active clock edge time
0.000 | 0.000 | | | | | clk_sys
0.000 | 0.000 | tCL | RR | 1 | IOB117[B] | clk_ibuf/I
0.952 | 0.952 | tINS | RR | 17287 | IOB117[B] | clk_ibuf/O
2.363 | 1.411 | tNET | RR | 1 | R35C65[0][A] | g_sound.u_note_manager/env_level_r_470_s0/CLK
2.375 | 0.012 | tHld | | 1 | R35C65[0][A] | g_sound.u_note_manager/env_level_r_470_s0

Path Statistics:

Clock Skew | 0.177
Hold Relationship | 0.000
Logic Level | 1
Arrival Clock Path Delay | cell: 0.952, 43.558%; route: 1.234, 56.442%
Arrival Data Path Delay | cell: 0.000, 0.000%; route: 0.257, 66.512%; tC2Q: 0.130, 33.488%
Required Clock Path Delay | cell: 0.952, 40.291%; route: 1.411, 59.709%

### Path5

Path Summary:

Slack | 0.202
Data Arrival Time | 2.580
Data Required Time | 2.379
From | g_sound.u_envelope_bank/env_level_o_503_s0
To | g_sound.u_note_manager/env_level_r_503_s0
Launch Clk | clk_sys:[R]
Latch Clk | clk_sys:[R]

Data Arrival Path:

AT | DELAY | TYPE | RF | FANOUT | LOC | NODE
0.000 | 0.000 | | | | | active clock edge time
0.000 | 0.000 | | | | | clk_sys
0.000 | 0.000 | tCL | RR | 1 | IOB117[B] | clk_ibuf/I
0.952 | 0.952 | tINS | RR | 17287 | IOB117[B] | clk_ibuf/O
2.193 | 1.241 | tNET | RR | 1 | R43C67[1][A] | g_sound.u_envelope_bank/env_level_o_503_s0/CLK
2.323 | 0.130 | tC2Q | RR | 1 | R43C67[1][A] | g_sound.u_envelope_bank/env_level_o_503_s0/Q
2.580 | 0.257 | tNET | RR | 1 | R35C66[2][A] | g_sound.u_note_manager/env_level_r_503_s0/D

Data Required Path:

AT | DELAY | TYPE | RF | FANOUT | LOC | NODE
0.000 | 0.000 | | | | | active clock edge time
0.000 | 0.000 | | | | | clk_sys
0.000 | 0.000 | tCL | RR | 1 | IOB117[B] | clk_ibuf/I
0.952 | 0.952 | tINS | RR | 17287 | IOB117[B] | clk_ibuf/O
2.367 | 1.415 | tNET | RR | 1 | R35C66[2][A] | g_sound.u_note_manager/env_level_r_503_s0/CLK
2.379 | 0.012 | tHld | | 1 | R35C66[2][A] | g_sound.u_note_manager/env_level_r_503_s0

Path Statistics:

Clock Skew | 0.174
Hold Relationship | 0.000
Logic Level | 1
Arrival Clock Path Delay | cell: 0.952, 43.415%; route: 1.241, 56.585%
Arrival Data Path Delay | cell: 0.000, 0.000%; route: 0.257, 66.512%; tC2Q: 0.130, 33.488%
Required Clock Path Delay | cell: 0.952, 40.230%; route: 1.415, 59.770%

### Path6

Path Summary:

Slack | 0.204
Data Arrival Time | 2.603
Data Required Time | 2.399
From | g_sound.u_looper/rd_ptr_r_2_s0
To | g_sound.u_looper/ep_mem_ep_mem_0_4_s
Launch Clk | clk_sys:[R]
Latch Clk | clk_sys:[R]

Data Arrival Path:

AT | DELAY | TYPE | RF | FANOUT | LOC | NODE
0.000 | 0.000 | | | | | active clock edge time
0.000 | 0.000 | | | | | clk_sys
0.000 | 0.000 | tCL | RR | 1 | IOB117[B] | clk_ibuf/I
0.952 | 0.952 | tINS | RR | 17287 | IOB117[B] | clk_ibuf/O
2.190 | 1.237 | tNET | RR | 1 | R41C36[0][A] | g_sound.u_looper/rd_ptr_r_2_s0/CLK
2.319 | 0.130 | tC2Q | RR | 20 | R41C36[0][A] | g_sound.u_looper/rd_ptr_r_2_s0/Q
2.603 | 0.283 | tNET | RR | 1 | BSRAM_R38[6][B] | g_sound.u_looper/ep_mem_ep_mem_0_4_s/ADB[5]

Data Required Path:

AT | DELAY | TYPE | RF | FANOUT | LOC | NODE
0.000 | 0.000 | | | | | active clock edge time
0.000 | 0.000 | | | | | clk_sys
0.000 | 0.000 | tCL | RR | 1 | IOB117[B] | clk_ibuf/I
0.952 | 0.952 | tINS | RR | 17287 | IOB117[B] | clk_ibuf/O
2.367 | 1.415 | tNET | RR | 1 | BSRAM_R38[6][B] | g_sound.u_looper/ep_mem_ep_mem_0_4_s/CLKB
2.399 | 0.032 | tHld | | 1 | BSRAM_R38[6][B] | g_sound.u_looper/ep_mem_ep_mem_0_4_s

Path Statistics:

Clock Skew | 0.177
Hold Relationship | 0.000
Logic Level | 1
Arrival Clock Path Delay | cell: 0.952, 43.487%; route: 1.237, 56.513%
Arrival Data Path Delay | cell: 0.000, 0.000%; route: 0.283, 68.627%; tC2Q: 0.130, 31.373%
Required Clock Path Delay | cell: 0.952, 40.230%; route: 1.415, 59.770%

### Path7

Path Summary:

Slack | 0.207
Data Arrival Time | 3.081
Data Required Time | 2.874
From | u_hdmi/u_blue/symbol_7_s0
To | u_hdmi/u_serializer/lanes[0].u_oser
Launch Clk | pixel_clk:[R]
Latch Clk | pixel_clk:[R]

Data Arrival Path:

AT | DELAY | TYPE | RF | FANOUT | LOC | NODE
0.000 | 0.000 | | | | | active clock edge time
0.000 | 0.000 | | | | | pixel_clk
2.186 | 2.186 | tCL | RR | 340 | PLL_R[1] | u_hdmi/u_clk/u_pll/CLKOUT1
2.788 | 0.602 | tNET | RR | 1 | R26C146[0][A] | u_hdmi/u_blue/symbol_7_s0/CLK
2.918 | 0.130 | tC2Q | RR | 4 | R26C146[0][A] | u_hdmi/u_blue/symbol_7_s0/Q
3.081 | 0.163 | tNET | RR | 1 | IOR26[A] | u_hdmi/u_serializer/lanes[0].u_oser/D0

Data Required Path:

AT | DELAY | TYPE | RF | FANOUT | LOC | NODE
0.000 | 0.000 | | | | | active clock edge time
0.000 | 0.000 | | | | | pixel_clk
2.186 | 2.186 | tCL | RR | 340 | PLL_R[1] | u_hdmi/u_clk/u_pll/CLKOUT1
2.788 | 0.602 | tNET | RR | 1 | IOR26[A] | u_hdmi/u_serializer/lanes[0].u_oser/PCLK
2.874 | 0.085 | tHld | | 1 | IOR26[A] | u_hdmi/u_serializer/lanes[0].u_oser

Path Statistics:

Clock Skew | 0.000
Hold Relationship | 0.000
Logic Level | 1
Arrival Clock Path Delay | cell: 0.000, 0.000%; route: 0.602, 100.000%
Arrival Data Path Delay | cell: 0.000, 0.000%; route: 0.163, 55.692%; tC2Q: 0.130, 44.308%
Required Clock Path Delay | cell: 0.000, 0.000%; route: 0.602, 100.000%

### Path8

Path Summary:

Slack | 0.208
Data Arrival Time | 3.082
Data Required Time | 2.874
From | u_hdmi/u_blue/symbol_8_s0
To | u_hdmi/u_serializer/lanes[0].u_oser
Launch Clk | pixel_clk:[R]
Latch Clk | pixel_clk:[R]

Data Arrival Path:

AT | DELAY | TYPE | RF | FANOUT | LOC | NODE
0.000 | 0.000 | | | | | active clock edge time
0.000 | 0.000 | | | | | pixel_clk
2.186 | 2.186 | tCL | RR | 340 | PLL_R[1] | u_hdmi/u_clk/u_pll/CLKOUT1
2.795 | 0.609 | tNET | RR | 1 | R27C145[3][A] | u_hdmi/u_blue/symbol_8_s0/CLK
2.925 | 0.130 | tC2Q | RR | 1 | R27C145[3][A] | u_hdmi/u_blue/symbol_8_s0/Q
3.082 | 0.157 | tNET | RR | 1 | IOR26[A] | u_hdmi/u_serializer/lanes[0].u_oser/D8

Data Required Path:

AT | DELAY | TYPE | RF | FANOUT | LOC | NODE
0.000 | 0.000 | | | | | active clock edge time
0.000 | 0.000 | | | | | pixel_clk
2.186 | 2.186 | tCL | RR | 340 | PLL_R[1] | u_hdmi/u_clk/u_pll/CLKOUT1
2.788 | 0.602 | tNET | RR | 1 | IOR26[A] | u_hdmi/u_serializer/lanes[0].u_oser/PCLK
2.874 | 0.085 | tHld | | 1 | IOR26[A] | u_hdmi/u_serializer/lanes[0].u_oser

Path Statistics:

Clock Skew | -0.007
Hold Relationship | 0.000
Logic Level | 1
Arrival Clock Path Delay | cell: 0.000, 0.000%; route: 0.609, 100.000%
Arrival Data Path Delay | cell: 0.000, 0.000%; route: 0.157, 54.717%; tC2Q: 0.130, 45.283%
Required Clock Path Delay | cell: 0.000, 0.000%; route: 0.602, 100.000%

### Path9

Path Summary:

Slack | 0.211
Data Arrival Time | 2.589
Data Required Time | 2.379
From | g_sound.u_envelope_bank/env_level_o_486_s0
To | g_sound.u_note_manager/env_level_r_486_s0
Launch Clk | clk_sys:[R]
Latch Clk | clk_sys:[R]

Data Arrival Path:

AT | DELAY | TYPE | RF | FANOUT | LOC | NODE
0.000 | 0.000 | | | | | active clock edge time
0.000 | 0.000 | | | | | clk_sys
0.000 | 0.000 | tCL | RR | 1 | IOB117[B] | clk_ibuf/I
0.952 | 0.952 | tINS | RR | 17287 | IOB117[B] | clk_ibuf/O
2.193 | 1.241 | tNET | RR | 1 | R43C63[1][B] | g_sound.u_envelope_bank/env_level_o_486_s0/CLK
2.323 | 0.130 | tC2Q | RR | 1 | R43C63[1][B] | g_sound.u_envelope_bank/env_level_o_486_s0/Q
2.589 | 0.266 | tNET | RR | 1 | R35C64[1][B] | g_sound.u_note_manager/env_level_r_486_s0/D

Data Required Path:

AT | DELAY | TYPE | RF | FANOUT | LOC | NODE
0.000 | 0.000 | | | | | active clock edge time
0.000 | 0.000 | | | | | clk_sys
0.000 | 0.000 | tCL | RR | 1 | IOB117[B] | clk_ibuf/I
0.952 | 0.952 | tINS | RR | 17287 | IOB117[B] | clk_ibuf/O
2.367 | 1.415 | tNET | RR | 1 | R35C64[1][B] | g_sound.u_note_manager/env_level_r_486_s0/CLK
2.379 | 0.012 | tHld | | 1 | R35C64[1][B] | g_sound.u_note_manager/env_level_r_486_s0

Path Statistics:

Clock Skew | 0.174
Hold Relationship | 0.000
Logic Level | 1
Arrival Clock Path Delay | cell: 0.952, 43.415%; route: 1.241, 56.585%
Arrival Data Path Delay | cell: 0.000, 0.000%; route: 0.266, 67.273%; tC2Q: 0.130, 32.727%
Required Clock Path Delay | cell: 0.952, 40.230%; route: 1.415, 59.770%

### Path10

Path Summary:

Slack | 0.211
Data Arrival Time | 2.606
Data Required Time | 2.395
From | g_sound.u_looper/rd_ptr_r_9_s0
To | g_sound.u_looper/ep_mem_ep_mem_0_3_s
Launch Clk | clk_sys:[R]
Latch Clk | clk_sys:[R]

Data Arrival Path:

AT | DELAY | TYPE | RF | FANOUT | LOC | NODE
0.000 | 0.000 | | | | | active clock edge time
0.000 | 0.000 | | | | | clk_sys
0.000 | 0.000 | tCL | RR | 1 | IOB117[B] | clk_ibuf/I
0.952 | 0.952 | tINS | RR | 17287 | IOB117[B] | clk_ibuf/O
2.186 | 1.234 | tNET | RR | 1 | R42C37[1][B] | g_sound.u_looper/rd_ptr_r_9_s0/CLK
2.316 | 0.130 | tC2Q | RR | 19 | R42C37[1][B] | g_sound.u_looper/rd_ptr_r_9_s0/Q
2.606 | 0.291 | tNET | RR | 1 | BSRAM_R38[6][A] | g_sound.u_looper/ep_mem_ep_mem_0_3_s/ADB[12]

Data Required Path:

AT | DELAY | TYPE | RF | FANOUT | LOC | NODE
0.000 | 0.000 | | | | | active clock edge time
0.000 | 0.000 | | | | | clk_sys
0.000 | 0.000 | tCL | RR | 1 | IOB117[B] | clk_ibuf/I
0.952 | 0.952 | tINS | RR | 17287 | IOB117[B] | clk_ibuf/O
2.363 | 1.411 | tNET | RR | 1 | BSRAM_R38[6][A] | g_sound.u_looper/ep_mem_ep_mem_0_3_s/CLKB
2.395 | 0.032 | tHld | | 1 | BSRAM_R38[6][A] | g_sound.u_looper/ep_mem_ep_mem_0_3_s

Path Statistics:

Clock Skew | 0.177
Hold Relationship | 0.000
Logic Level | 1
Arrival Clock Path Delay | cell: 0.952, 43.558%; route: 1.234, 56.442%
Arrival Data Path Delay | cell: 0.000, 0.000%; route: 0.291, 69.165%; tC2Q: 0.130, 30.835%
Required Clock Path Delay | cell: 0.952, 40.291%; route: 1.411, 59.709%

### Path11

Path Summary:

Slack | 0.215
Data Arrival Time | 3.078
Data Required Time | 2.863
From | u_hdmi/u_blue/symbol_7_s0
To | u_hdmi/u_serializer/lanes[0].u_oser
Launch Clk | pixel_clk:[R]
Latch Clk | pixel_clk:[R]

Data Arrival Path:

AT | DELAY | TYPE | RF | FANOUT | LOC | NODE
0.000 | 0.000 | | | | | active clock edge time
0.000 | 0.000 | | | | | pixel_clk
2.186 | 2.186 | tCL | RR | 340 | PLL_R[1] | u_hdmi/u_clk/u_pll/CLKOUT1
2.788 | 0.602 | tNET | RR | 1 | R26C146[0][A] | u_hdmi/u_blue/symbol_7_s0/CLK
2.918 | 0.130 | tC2Q | RR | 4 | R26C146[0][A] | u_hdmi/u_blue/symbol_7_s0/Q
3.078 | 0.160 | tNET | RR | 1 | IOR26[A] | u_hdmi/u_serializer/lanes[0].u_oser/D5

Data Required Path:

AT | DELAY | TYPE | RF | FANOUT | LOC | NODE
0.000 | 0.000 | | | | | active clock edge time
0.000 | 0.000 | | | | | pixel_clk
2.186 | 2.186 | tCL | RR | 340 | PLL_R[1] | u_hdmi/u_clk/u_pll/CLKOUT1
2.788 | 0.602 | tNET | RR | 1 | IOR26[A] | u_hdmi/u_serializer/lanes[0].u_oser/PCLK
2.863 | 0.075 | tHld | | 1 | IOR26[A] | u_hdmi/u_serializer/lanes[0].u_oser

Path Statistics:

Clock Skew | 0.000
Hold Relationship | 0.000
Logic Level | 1
Arrival Clock Path Delay | cell: 0.000, 0.000%; route: 0.602, 100.000%
Arrival Data Path Delay | cell: 0.000, 0.000%; route: 0.160, 55.280%; tC2Q: 0.130, 44.720%
Required Clock Path Delay | cell: 0.000, 0.000%; route: 0.602, 100.000%

### Path12

Path Summary:

Slack | 0.218
Data Arrival Time | 3.081
Data Required Time | 2.863
From | u_hdmi/u_blue/symbol_7_s0
To | u_hdmi/u_serializer/lanes[0].u_oser
Launch Clk | pixel_clk:[R]
Latch Clk | pixel_clk:[R]

Data Arrival Path:

AT | DELAY | TYPE | RF | FANOUT | LOC | NODE
0.000 | 0.000 | | | | | active clock edge time
0.000 | 0.000 | | | | | pixel_clk
2.186 | 2.186 | tCL | RR | 340 | PLL_R[1] | u_hdmi/u_clk/u_pll/CLKOUT1
2.788 | 0.602 | tNET | RR | 1 | R26C146[0][A] | u_hdmi/u_blue/symbol_7_s0/CLK
2.918 | 0.130 | tC2Q | RR | 4 | R26C146[0][A] | u_hdmi/u_blue/symbol_7_s0/Q
3.081 | 0.163 | tNET | RR | 1 | IOR26[A] | u_hdmi/u_serializer/lanes[0].u_oser/D1

Data Required Path:

AT | DELAY | TYPE | RF | FANOUT | LOC | NODE
0.000 | 0.000 | | | | | active clock edge time
0.000 | 0.000 | | | | | pixel_clk
2.186 | 2.186 | tCL | RR | 340 | PLL_R[1] | u_hdmi/u_clk/u_pll/CLKOUT1
2.788 | 0.602 | tNET | RR | 1 | IOR26[A] | u_hdmi/u_serializer/lanes[0].u_oser/PCLK
2.863 | 0.075 | tHld | | 1 | IOR26[A] | u_hdmi/u_serializer/lanes[0].u_oser

Path Statistics:

Clock Skew | 0.000
Hold Relationship | 0.000
Logic Level | 1
Arrival Clock Path Delay | cell: 0.000, 0.000%; route: 0.602, 100.000%
Arrival Data Path Delay | cell: 0.000, 0.000%; route: 0.163, 55.692%; tC2Q: 0.130, 44.308%
Required Clock Path Delay | cell: 0.000, 0.000%; route: 0.602, 100.000%

### Path13

Path Summary:

Slack | 0.247
Data Arrival Time | 2.456
Data Required Time | 2.209
From | u_led_indicator/beat_t_1_s1
To | u_led_indicator/beat_t_1_s1
Launch Clk | clk_sys:[R]
Latch Clk | clk_sys:[R]

Data Arrival Path:

AT | DELAY | TYPE | RF | FANOUT | LOC | NODE
0.000 | 0.000 | | | | | active clock edge time
0.000 | 0.000 | | | | | clk_sys
0.000 | 0.000 | tCL | RR | 1 | IOB117[B] | clk_ibuf/I
0.952 | 0.952 | tINS | RR | 17287 | IOB117[B] | clk_ibuf/O
2.186 | 1.234 | tNET | RR | 1 | R58C33[0][A] | u_led_indicator/beat_t_1_s1/CLK
2.313 | 0.127 | tC2Q | RF | 4 | R58C33[0][A] | u_led_indicator/beat_t_1_s1/Q
2.318 | 0.005 | tNET | FF | 1 | R58C33[0][A] | u_led_indicator/n102_s6/I3
2.456 | 0.138 | tINS | FF | 1 | R58C33[0][A] | u_led_indicator/n102_s6/F
2.456 | 0.000 | tNET | FF | 1 | R58C33[0][A] | u_led_indicator/beat_t_1_s1/D

Data Required Path:

AT | DELAY | TYPE | RF | FANOUT | LOC | NODE
0.000 | 0.000 | | | | | active clock edge time
0.000 | 0.000 | | | | | clk_sys
0.000 | 0.000 | tCL | RR | 1 | IOB117[B] | clk_ibuf/I
0.952 | 0.952 | tINS | RR | 17287 | IOB117[B] | clk_ibuf/O
2.186 | 1.234 | tNET | RR | 1 | R58C33[0][A] | u_led_indicator/beat_t_1_s1/CLK
2.209 | 0.022 | tHld | | 1 | R58C33[0][A] | u_led_indicator/beat_t_1_s1

Path Statistics:

Clock Skew | 0.000
Hold Relationship | 0.000
Logic Level | 2
Arrival Clock Path Delay | cell: 0.952, 43.558%; route: 1.234, 56.442%
Arrival Data Path Delay | cell: 0.138, 51.000%; route: 0.005, 2.000%; tC2Q: 0.127, 47.000%
Required Clock Path Delay | cell: 0.952, 43.558%; route: 1.234, 56.442%

### Path14

Path Summary:

Slack | 0.247
Data Arrival Time | 2.456
Data Required Time | 2.209
From | u_led_indicator/beat_t_4_s1
To | u_led_indicator/beat_t_4_s1
Launch Clk | clk_sys:[R]
Latch Clk | clk_sys:[R]

Data Arrival Path:

AT | DELAY | TYPE | RF | FANOUT | LOC | NODE
0.000 | 0.000 | | | | | active clock edge time
0.000 | 0.000 | | | | | clk_sys
0.000 | 0.000 | tCL | RR | 1 | IOB117[B] | clk_ibuf/I
0.952 | 0.952 | tINS | RR | 17287 | IOB117[B] | clk_ibuf/O
2.186 | 1.234 | tNET | RR | 1 | R57C33[0][A] | u_led_indicator/beat_t_4_s1/CLK
2.313 | 0.127 | tC2Q | RF | 4 | R57C33[0][A] | u_led_indicator/beat_t_4_s1/Q
2.318 | 0.005 | tNET | FF | 1 | R57C33[0][A] | u_led_indicator/n99_s7/I3
2.456 | 0.138 | tINS | FF | 1 | R57C33[0][A] | u_led_indicator/n99_s7/F
2.456 | 0.000 | tNET | FF | 1 | R57C33[0][A] | u_led_indicator/beat_t_4_s1/D

Data Required Path:

AT | DELAY | TYPE | RF | FANOUT | LOC | NODE
0.000 | 0.000 | | | | | active clock edge time
0.000 | 0.000 | | | | | clk_sys
0.000 | 0.000 | tCL | RR | 1 | IOB117[B] | clk_ibuf/I
0.952 | 0.952 | tINS | RR | 17287 | IOB117[B] | clk_ibuf/O
2.186 | 1.234 | tNET | RR | 1 | R57C33[0][A] | u_led_indicator/beat_t_4_s1/CLK
2.209 | 0.022 | tHld | | 1 | R57C33[0][A] | u_led_indicator/beat_t_4_s1

Path Statistics:

Clock Skew | 0.000
Hold Relationship | 0.000
Logic Level | 2
Arrival Clock Path Delay | cell: 0.952, 43.558%; route: 1.234, 56.442%
Arrival Data Path Delay | cell: 0.138, 51.000%; route: 0.005, 2.000%; tC2Q: 0.127, 47.000%
Required Clock Path Delay | cell: 0.952, 43.558%; route: 1.234, 56.442%

### Path15

Path Summary:

Slack | 0.247
Data Arrival Time | 2.460
Data Required Time | 2.212
From | u_led_indicator/beat_t_11_s1
To | u_led_indicator/beat_t_11_s1
Launch Clk | clk_sys:[R]
Latch Clk | clk_sys:[R]

Data Arrival Path:

AT | DELAY | TYPE | RF | FANOUT | LOC | NODE
0.000 | 0.000 | | | | | active clock edge time
0.000 | 0.000 | | | | | clk_sys
0.000 | 0.000 | tCL | RR | 1 | IOB117[B] | clk_ibuf/I
0.952 | 0.952 | tINS | RR | 17287 | IOB117[B] | clk_ibuf/O
2.190 | 1.237 | tNET | RR | 1 | R57C34[1][A] | u_led_indicator/beat_t_11_s1/CLK
2.317 | 0.127 | tC2Q | RF | 3 | R57C34[1][A] | u_led_indicator/beat_t_11_s1/Q
2.322 | 0.005 | tNET | FF | 1 | R57C34[1][A] | u_led_indicator/n115_s1/I3
2.460 | 0.138 | tINS | FF | 1 | R57C34[1][A] | u_led_indicator/n115_s1/F
2.460 | 0.000 | tNET | FF | 1 | R57C34[1][A] | u_led_indicator/beat_t_11_s1/D

Data Required Path:

AT | DELAY | TYPE | RF | FANOUT | LOC | NODE
0.000 | 0.000 | | | | | active clock edge time
0.000 | 0.000 | | | | | clk_sys
0.000 | 0.000 | tCL | RR | 1 | IOB117[B] | clk_ibuf/I
0.952 | 0.952 | tINS | RR | 17287 | IOB117[B] | clk_ibuf/O
2.190 | 1.237 | tNET | RR | 1 | R57C34[1][A] | u_led_indicator/beat_t_11_s1/CLK
2.212 | 0.022 | tHld | | 1 | R57C34[1][A] | u_led_indicator/beat_t_11_s1

Path Statistics:

Clock Skew | 0.000
Hold Relationship | 0.000
Logic Level | 2
Arrival Clock Path Delay | cell: 0.952, 43.487%; route: 1.237, 56.513%
Arrival Data Path Delay | cell: 0.138, 51.000%; route: 0.005, 2.000%; tC2Q: 0.127, 47.000%
Required Clock Path Delay | cell: 0.952, 43.487%; route: 1.237, 56.513%

### Path16

Path Summary:

Slack | 0.247
Data Arrival Time | 2.460
Data Required Time | 2.212
From | u_led_indicator/beat_t_5_s0
To | u_led_indicator/beat_t_5_s0
Launch Clk | clk_sys:[R]
Latch Clk | clk_sys:[R]

Data Arrival Path:

AT | DELAY | TYPE | RF | FANOUT | LOC | NODE
0.000 | 0.000 | | | | | active clock edge time
0.000 | 0.000 | | | | | clk_sys
0.000 | 0.000 | tCL | RR | 1 | IOB117[B] | clk_ibuf/I
0.952 | 0.952 | tINS | RR | 17287 | IOB117[B] | clk_ibuf/O
2.190 | 1.237 | tNET | RR | 1 | R58C34[1][A] | u_led_indicator/beat_t_5_s0/CLK
2.317 | 0.127 | tC2Q | RF | 3 | R58C34[1][A] | u_led_indicator/beat_t_5_s0/Q
2.322 | 0.005 | tNET | FF | 1 | R58C34[1][A] | u_led_indicator/n98_s4/I2
2.460 | 0.138 | tINS | FF | 1 | R58C34[1][A] | u_led_indicator/n98_s4/F
2.460 | 0.000 | tNET | FF | 1 | R58C34[1][A] | u_led_indicator/beat_t_5_s0/D

Data Required Path:

AT | DELAY | TYPE | RF | FANOUT | LOC | NODE
0.000 | 0.000 | | | | | active clock edge time
0.000 | 0.000 | | | | | clk_sys
0.000 | 0.000 | tCL | RR | 1 | IOB117[B] | clk_ibuf/I
0.952 | 0.952 | tINS | RR | 17287 | IOB117[B] | clk_ibuf/O
2.190 | 1.237 | tNET | RR | 1 | R58C34[1][A] | u_led_indicator/beat_t_5_s0/CLK
2.212 | 0.022 | tHld | | 1 | R58C34[1][A] | u_led_indicator/beat_t_5_s0

Path Statistics:

Clock Skew | 0.000
Hold Relationship | 0.000
Logic Level | 2
Arrival Clock Path Delay | cell: 0.952, 43.487%; route: 1.237, 56.513%
Arrival Data Path Delay | cell: 0.138, 51.000%; route: 0.005, 2.000%; tC2Q: 0.127, 47.000%
Required Clock Path Delay | cell: 0.952, 43.487%; route: 1.237, 56.513%

### Path17

Path Summary:

Slack | 0.247
Data Arrival Time | 2.456
Data Required Time | 2.209
From | u_ws2812/bit_t_5_s1
To | u_ws2812/bit_t_5_s1
Launch Clk | clk_sys:[R]
Latch Clk | clk_sys:[R]

Data Arrival Path:

AT | DELAY | TYPE | RF | FANOUT | LOC | NODE
0.000 | 0.000 | | | | | active clock edge time
0.000 | 0.000 | | | | | clk_sys
0.000 | 0.000 | tCL | RR | 1 | IOB117[B] | clk_ibuf/I
0.952 | 0.952 | tINS | RR | 17287 | IOB117[B] | clk_ibuf/O
2.186 | 1.234 | tNET | RR | 1 | R59C37[0][A] | u_ws2812/bit_t_5_s1/CLK
2.313 | 0.127 | tC2Q | RF | 4 | R59C37[0][A] | u_ws2812/bit_t_5_s1/Q
2.318 | 0.005 | tNET | FF | 1 | R59C37[0][A] | u_ws2812/n409_s2/I1
2.456 | 0.138 | tINS | FF | 1 | R59C37[0][A] | u_ws2812/n409_s2/F
2.456 | 0.000 | tNET | FF | 1 | R59C37[0][A] | u_ws2812/bit_t_5_s1/D

Data Required Path:

AT | DELAY | TYPE | RF | FANOUT | LOC | NODE
0.000 | 0.000 | | | | | active clock edge time
0.000 | 0.000 | | | | | clk_sys
0.000 | 0.000 | tCL | RR | 1 | IOB117[B] | clk_ibuf/I
0.952 | 0.952 | tINS | RR | 17287 | IOB117[B] | clk_ibuf/O
2.186 | 1.234 | tNET | RR | 1 | R59C37[0][A] | u_ws2812/bit_t_5_s1/CLK
2.209 | 0.022 | tHld | | 1 | R59C37[0][A] | u_ws2812/bit_t_5_s1

Path Statistics:

Clock Skew | 0.000
Hold Relationship | 0.000
Logic Level | 2
Arrival Clock Path Delay | cell: 0.952, 43.558%; route: 1.234, 56.442%
Arrival Data Path Delay | cell: 0.138, 51.000%; route: 0.005, 2.000%; tC2Q: 0.127, 47.000%
Required Clock Path Delay | cell: 0.952, 43.558%; route: 1.234, 56.442%

### Path18

Path Summary:

Slack | 0.247
Data Arrival Time | 2.463
Data Required Time | 2.216
From | u_ws2812/bit_i_0_s1
To | u_ws2812/bit_i_0_s1
Launch Clk | clk_sys:[R]
Latch Clk | clk_sys:[R]

Data Arrival Path:

AT | DELAY | TYPE | RF | FANOUT | LOC | NODE
0.000 | 0.000 | | | | | active clock edge time
0.000 | 0.000 | | | | | clk_sys
0.000 | 0.000 | tCL | RR | 1 | IOB117[B] | clk_ibuf/I
0.952 | 0.952 | tINS | RR | 17287 | IOB117[B] | clk_ibuf/O
2.193 | 1.241 | tNET | RR | 1 | R62C39[1][A] | u_ws2812/bit_i_0_s1/CLK
2.320 | 0.127 | tC2Q | RF | 5 | R62C39[1][A] | u_ws2812/bit_i_0_s1/Q
2.326 | 0.005 | tNET | FF | 1 | R62C39[1][A] | u_ws2812/n536_s9/I0
2.463 | 0.138 | tINS | FF | 1 | R62C39[1][A] | u_ws2812/n536_s9/F
2.463 | 0.000 | tNET | FF | 1 | R62C39[1][A] | u_ws2812/bit_i_0_s1/D

Data Required Path:

AT | DELAY | TYPE | RF | FANOUT | LOC | NODE
0.000 | 0.000 | | | | | active clock edge time
0.000 | 0.000 | | | | | clk_sys
0.000 | 0.000 | tCL | RR | 1 | IOB117[B] | clk_ibuf/I
0.952 | 0.952 | tINS | RR | 17287 | IOB117[B] | clk_ibuf/O
2.193 | 1.241 | tNET | RR | 1 | R62C39[1][A] | u_ws2812/bit_i_0_s1/CLK
2.216 | 0.022 | tHld | | 1 | R62C39[1][A] | u_ws2812/bit_i_0_s1

Path Statistics:

Clock Skew | 0.000
Hold Relationship | 0.000
Logic Level | 2
Arrival Clock Path Delay | cell: 0.952, 43.415%; route: 1.241, 56.585%
Arrival Data Path Delay | cell: 0.138, 51.000%; route: 0.005, 2.000%; tC2Q: 0.127, 47.000%
Required Clock Path Delay | cell: 0.952, 43.415%; route: 1.241, 56.585%

### Path19

Path Summary:

Slack | 0.247
Data Arrival Time | 2.463
Data Required Time | 2.216
From | u_ws2812/led_i_0_s1
To | u_ws2812/led_i_0_s1
Launch Clk | clk_sys:[R]
Latch Clk | clk_sys:[R]

Data Arrival Path:

AT | DELAY | TYPE | RF | FANOUT | LOC | NODE
0.000 | 0.000 | | | | | active clock edge time
0.000 | 0.000 | | | | | clk_sys
0.000 | 0.000 | tCL | RR | 1 | IOB117[B] | clk_ibuf/I
0.952 | 0.952 | tINS | RR | 17287 | IOB117[B] | clk_ibuf/O
2.193 | 1.241 | tNET | RR | 1 | R59C35[0][A] | u_ws2812/led_i_0_s1/CLK
2.320 | 0.127 | tC2Q | RF | 7 | R59C35[0][A] | u_ws2812/led_i_0_s1/Q
2.326 | 0.005 | tNET | FF | 1 | R59C35[0][A] | u_ws2812/n547_s7/I0
2.463 | 0.138 | tINS | FF | 1 | R59C35[0][A] | u_ws2812/n547_s7/F
2.463 | 0.000 | tNET | FF | 1 | R59C35[0][A] | u_ws2812/led_i_0_s1/D

Data Required Path:

AT | DELAY | TYPE | RF | FANOUT | LOC | NODE
0.000 | 0.000 | | | | | active clock edge time
0.000 | 0.000 | | | | | clk_sys
0.000 | 0.000 | tCL | RR | 1 | IOB117[B] | clk_ibuf/I
0.952 | 0.952 | tINS | RR | 17287 | IOB117[B] | clk_ibuf/O
2.193 | 1.241 | tNET | RR | 1 | R59C35[0][A] | u_ws2812/led_i_0_s1/CLK
2.216 | 0.022 | tHld | | 1 | R59C35[0][A] | u_ws2812/led_i_0_s1

Path Statistics:

Clock Skew | 0.000
Hold Relationship | 0.000
Logic Level | 2
Arrival Clock Path Delay | cell: 0.952, 43.415%; route: 1.241, 56.585%
Arrival Data Path Delay | cell: 0.138, 51.000%; route: 0.005, 2.000%; tC2Q: 0.127, 47.000%
Required Clock Path Delay | cell: 0.952, 43.415%; route: 1.241, 56.585%

### Path20

Path Summary:

Slack | 0.247
Data Arrival Time | 2.456
Data Required Time | 2.209
From | u_ws2812/rst_t_4_s0
To | u_ws2812/rst_t_4_s0
Launch Clk | clk_sys:[R]
Latch Clk | clk_sys:[R]

Data Arrival Path:

AT | DELAY | TYPE | RF | FANOUT | LOC | NODE
0.000 | 0.000 | | | | | active clock edge time
0.000 | 0.000 | | | | | clk_sys
0.000 | 0.000 | tCL | RR | 1 | IOB117[B] | clk_ibuf/I
0.952 | 0.952 | tINS | RR | 17287 | IOB117[B] | clk_ibuf/O
2.186 | 1.234 | tNET | RR | 1 | R58C41[0][A] | u_ws2812/rst_t_4_s0/CLK
2.313 | 0.127 | tC2Q | RF | 2 | R58C41[0][A] | u_ws2812/rst_t_4_s0/Q
2.318 | 0.005 | tNET | FF | 1 | R58C41[0][A] | u_ws2812/n502_s4/I1
2.456 | 0.138 | tINS | FF | 1 | R58C41[0][A] | u_ws2812/n502_s4/F
2.456 | 0.000 | tNET | FF | 1 | R58C41[0][A] | u_ws2812/rst_t_4_s0/D

Data Required Path:

AT | DELAY | TYPE | RF | FANOUT | LOC | NODE
0.000 | 0.000 | | | | | active clock edge time
0.000 | 0.000 | | | | | clk_sys
0.000 | 0.000 | tCL | RR | 1 | IOB117[B] | clk_ibuf/I
0.952 | 0.952 | tINS | RR | 17287 | IOB117[B] | clk_ibuf/O
2.186 | 1.234 | tNET | RR | 1 | R58C41[0][A] | u_ws2812/rst_t_4_s0/CLK
2.209 | 0.022 | tHld | | 1 | R58C41[0][A] | u_ws2812/rst_t_4_s0

Path Statistics:

Clock Skew | 0.000
Hold Relationship | 0.000
Logic Level | 2
Arrival Clock Path Delay | cell: 0.952, 43.558%; route: 1.234, 56.442%
Arrival Data Path Delay | cell: 0.138, 51.000%; route: 0.005, 2.000%; tC2Q: 0.127, 47.000%
Required Clock Path Delay | cell: 0.952, 43.558%; route: 1.234, 56.442%

### Path21

Path Summary:

Slack | 0.247
Data Arrival Time | 2.456
Data Required Time | 2.209
From | u_ws2812/rst_t_8_s0
To | u_ws2812/rst_t_8_s0
Launch Clk | clk_sys:[R]
Latch Clk | clk_sys:[R]

Data Arrival Path:

AT | DELAY | TYPE | RF | FANOUT | LOC | NODE
0.000 | 0.000 | | | | | active clock edge time
0.000 | 0.000 | | | | | clk_sys
0.000 | 0.000 | tCL | RR | 1 | IOB117[B] | clk_ibuf/I
0.952 | 0.952 | tINS | RR | 17287 | IOB117[B] | clk_ibuf/O
2.186 | 1.234 | tNET | RR | 1 | R55C41[0][A] | u_ws2812/rst_t_8_s0/CLK
2.313 | 0.127 | tC2Q | RF | 5 | R55C41[0][A] | u_ws2812/rst_t_8_s0/Q
2.318 | 0.005 | tNET | FF | 1 | R55C41[0][A] | u_ws2812/n498_s4/I0
2.456 | 0.138 | tINS | FF | 1 | R55C41[0][A] | u_ws2812/n498_s4/F
2.456 | 0.000 | tNET | FF | 1 | R55C41[0][A] | u_ws2812/rst_t_8_s0/D

Data Required Path:

AT | DELAY | TYPE | RF | FANOUT | LOC | NODE
0.000 | 0.000 | | | | | active clock edge time
0.000 | 0.000 | | | | | clk_sys
0.000 | 0.000 | tCL | RR | 1 | IOB117[B] | clk_ibuf/I
0.952 | 0.952 | tINS | RR | 17287 | IOB117[B] | clk_ibuf/O
2.186 | 1.234 | tNET | RR | 1 | R55C41[0][A] | u_ws2812/rst_t_8_s0/CLK
2.209 | 0.022 | tHld | | 1 | R55C41[0][A] | u_ws2812/rst_t_8_s0

Path Statistics:

Clock Skew | 0.000
Hold Relationship | 0.000
Logic Level | 2
Arrival Clock Path Delay | cell: 0.952, 43.558%; route: 1.234, 56.442%
Arrival Data Path Delay | cell: 0.138, 51.000%; route: 0.005, 2.000%; tC2Q: 0.127, 47.000%
Required Clock Path Delay | cell: 0.952, 43.558%; route: 1.234, 56.442%

### Path22

Path Summary:

Slack | 0.247
Data Arrival Time | 2.460
Data Required Time | 2.212
From | u_ws2812/rst_t_13_s0
To | u_ws2812/rst_t_13_s0
Launch Clk | clk_sys:[R]
Latch Clk | clk_sys:[R]

Data Arrival Path:

AT | DELAY | TYPE | RF | FANOUT | LOC | NODE
0.000 | 0.000 | | | | | active clock edge time
0.000 | 0.000 | | | | | clk_sys
0.000 | 0.000 | tCL | RR | 1 | IOB117[B] | clk_ibuf/I
0.952 | 0.952 | tINS | RR | 17287 | IOB117[B] | clk_ibuf/O
2.190 | 1.237 | tNET | RR | 1 | R59C40[0][A] | u_ws2812/rst_t_13_s0/CLK
2.317 | 0.127 | tC2Q | RF | 3 | R59C40[0][A] | u_ws2812/rst_t_13_s0/Q
2.322 | 0.005 | tNET | FF | 1 | R59C40[0][A] | u_ws2812/n493_s4/I1
2.460 | 0.138 | tINS | FF | 1 | R59C40[0][A] | u_ws2812/n493_s4/F
2.460 | 0.000 | tNET | FF | 1 | R59C40[0][A] | u_ws2812/rst_t_13_s0/D

Data Required Path:

AT | DELAY | TYPE | RF | FANOUT | LOC | NODE
0.000 | 0.000 | | | | | active clock edge time
0.000 | 0.000 | | | | | clk_sys
0.000 | 0.000 | tCL | RR | 1 | IOB117[B] | clk_ibuf/I
0.952 | 0.952 | tINS | RR | 17287 | IOB117[B] | clk_ibuf/O
2.190 | 1.237 | tNET | RR | 1 | R59C40[0][A] | u_ws2812/rst_t_13_s0/CLK
2.212 | 0.022 | tHld | | 1 | R59C40[0][A] | u_ws2812/rst_t_13_s0

Path Statistics:

Clock Skew | 0.000
Hold Relationship | 0.000
Logic Level | 2
Arrival Clock Path Delay | cell: 0.952, 43.487%; route: 1.237, 56.513%
Arrival Data Path Delay | cell: 0.138, 51.000%; route: 0.005, 2.000%; tC2Q: 0.127, 47.000%
Required Clock Path Delay | cell: 0.952, 43.487%; route: 1.237, 56.513%

### Path23

Path Summary:

Slack | 0.247
Data Arrival Time | 2.460
Data Required Time | 2.212
From | u_i2s_tx/bit_cnt_4_s0
To | u_i2s_tx/bit_cnt_4_s0
Launch Clk | clk_sys:[R]
Latch Clk | clk_sys:[R]

Data Arrival Path:

AT | DELAY | TYPE | RF | FANOUT | LOC | NODE
0.000 | 0.000 | | | | | active clock edge time
0.000 | 0.000 | | | | | clk_sys
0.000 | 0.000 | tCL | RR | 1 | IOB117[B] | clk_ibuf/I
0.952 | 0.952 | tINS | RR | 17287 | IOB117[B] | clk_ibuf/O
2.190 | 1.237 | tNET | RR | 1 | R61C127[0][A] | u_i2s_tx/bit_cnt_4_s0/CLK
2.317 | 0.127 | tC2Q | RF | 3 | R61C127[0][A] | u_i2s_tx/bit_cnt_4_s0/Q
2.322 | 0.005 | tNET | FF | 1 | R61C127[0][A] | u_i2s_tx/n54_s2/I1
2.460 | 0.138 | tINS | FF | 1 | R61C127[0][A] | u_i2s_tx/n54_s2/F
2.460 | 0.000 | tNET | FF | 1 | R61C127[0][A] | u_i2s_tx/bit_cnt_4_s0/D

Data Required Path:

AT | DELAY | TYPE | RF | FANOUT | LOC | NODE
0.000 | 0.000 | | | | | active clock edge time
0.000 | 0.000 | | | | | clk_sys
0.000 | 0.000 | tCL | RR | 1 | IOB117[B] | clk_ibuf/I
0.952 | 0.952 | tINS | RR | 17287 | IOB117[B] | clk_ibuf/O
2.190 | 1.237 | tNET | RR | 1 | R61C127[0][A] | u_i2s_tx/bit_cnt_4_s0/CLK
2.212 | 0.022 | tHld | | 1 | R61C127[0][A] | u_i2s_tx/bit_cnt_4_s0

Path Statistics:

Clock Skew | 0.000
Hold Relationship | 0.000
Logic Level | 2
Arrival Clock Path Delay | cell: 0.952, 43.487%; route: 1.237, 56.513%
Arrival Data Path Delay | cell: 0.138, 51.000%; route: 0.005, 2.000%; tC2Q: 0.127, 47.000%
Required Clock Path Delay | cell: 0.952, 43.487%; route: 1.237, 56.513%

### Path24

Path Summary:

Slack | 0.247
Data Arrival Time | 2.460
Data Required Time | 2.212
From | g_sound.u_tdm_render_mixer/norm_gain_r_13_s0
To | g_sound.u_tdm_render_mixer/norm_gain_r_13_s0
Launch Clk | clk_sys:[R]
Latch Clk | clk_sys:[R]

Data Arrival Path:

AT | DELAY | TYPE | RF | FANOUT | LOC | NODE
0.000 | 0.000 | | | | | active clock edge time
0.000 | 0.000 | | | | | clk_sys
0.000 | 0.000 | tCL | RR | 1 | IOB117[B] | clk_ibuf/I
0.952 | 0.952 | tINS | RR | 17287 | IOB117[B] | clk_ibuf/O
2.190 | 1.237 | tNET | RR | 1 | R60C141[1][A] | g_sound.u_tdm_render_mixer/norm_gain_r_13_s0/CLK
2.317 | 0.127 | tC2Q | RF | 6 | R60C141[1][A] | g_sound.u_tdm_render_mixer/norm_gain_r_13_s0/Q
2.322 | 0.005 | tNET | FF | 1 | R60C141[1][A] | g_sound.u_tdm_render_mixer/n1615_s0/I2
2.460 | 0.138 | tINS | FF | 1 | R60C141[1][A] | g_sound.u_tdm_render_mixer/n1615_s0/F
2.460 | 0.000 | tNET | FF | 1 | R60C141[1][A] | g_sound.u_tdm_render_mixer/norm_gain_r_13_s0/D

Data Required Path:

AT | DELAY | TYPE | RF | FANOUT | LOC | NODE
0.000 | 0.000 | | | | | active clock edge time
0.000 | 0.000 | | | | | clk_sys
0.000 | 0.000 | tCL | RR | 1 | IOB117[B] | clk_ibuf/I
0.952 | 0.952 | tINS | RR | 17287 | IOB117[B] | clk_ibuf/O
2.190 | 1.237 | tNET | RR | 1 | R60C141[1][A] | g_sound.u_tdm_render_mixer/norm_gain_r_13_s0/CLK
2.212 | 0.022 | tHld | | 1 | R60C141[1][A] | g_sound.u_tdm_render_mixer/norm_gain_r_13_s0

Path Statistics:

Clock Skew | 0.000
Hold Relationship | 0.000
Logic Level | 2
Arrival Clock Path Delay | cell: 0.952, 43.487%; route: 1.237, 56.513%
Arrival Data Path Delay | cell: 0.138, 51.000%; route: 0.005, 2.000%; tC2Q: 0.127, 47.000%
Required Clock Path Delay | cell: 0.952, 43.487%; route: 1.237, 56.513%

### Path25

Path Summary:

Slack | 0.247
Data Arrival Time | 2.456
Data Required Time | 2.209
From | g_sound.u_perc_env_bank/gen_perc[3].level_r_6_s0
To | g_sound.u_perc_env_bank/gen_perc[3].level_r_6_s0
Launch Clk | clk_sys:[R]
Latch Clk | clk_sys:[R]

Data Arrival Path:

AT | DELAY | TYPE | RF | FANOUT | LOC | NODE
0.000 | 0.000 | | | | | active clock edge time
0.000 | 0.000 | | | | | clk_sys
0.000 | 0.000 | tCL | RR | 1 | IOB117[B] | clk_ibuf/I
0.952 | 0.952 | tINS | RR | 17287 | IOB117[B] | clk_ibuf/O
2.186 | 1.234 | tNET | RR | 1 | R53C146[1][A] | g_sound.u_perc_env_bank/gen_perc[3].level_r_6_s0/CLK
2.313 | 0.127 | tC2Q | RF | 4 | R53C146[1][A] | g_sound.u_perc_env_bank/gen_perc[3].level_r_6_s0/Q
2.318 | 0.005 | tNET | FF | 1 | R53C146[1][A] | g_sound.u_perc_env_bank/n1220_s2/I2
2.456 | 0.138 | tINS | FF | 1 | R53C146[1][A] | g_sound.u_perc_env_bank/n1220_s2/F
2.456 | 0.000 | tNET | FF | 1 | R53C146[1][A] | g_sound.u_perc_env_bank/gen_perc[3].level_r_6_s0/D

Data Required Path:

AT | DELAY | TYPE | RF | FANOUT | LOC | NODE
0.000 | 0.000 | | | | | active clock edge time
0.000 | 0.000 | | | | | clk_sys
0.000 | 0.000 | tCL | RR | 1 | IOB117[B] | clk_ibuf/I
0.952 | 0.952 | tINS | RR | 17287 | IOB117[B] | clk_ibuf/O
2.186 | 1.234 | tNET | RR | 1 | R53C146[1][A] | g_sound.u_perc_env_bank/gen_perc[3].level_r_6_s0/CLK
2.209 | 0.022 | tHld | | 1 | R53C146[1][A] | g_sound.u_perc_env_bank/gen_perc[3].level_r_6_s0

Path Statistics:

Clock Skew | 0.000
Hold Relationship | 0.000
Logic Level | 2
Arrival Clock Path Delay | cell: 0.952, 43.558%; route: 1.234, 56.442%
Arrival Data Path Delay | cell: 0.138, 51.000%; route: 0.005, 2.000%; tC2Q: 0.127, 47.000%
Required Clock Path Delay | cell: 0.952, 43.558%; route: 1.234, 56.442%

### Recovery Analysis Report

#### Report Command:report_timing -recovery -max_paths 25 -max_common_paths 1

### Path1

Path Summary:

Slack | 0.086
Data Arrival Time | 7.911
Data Required Time | 7.998
From | u_hdmi/rstn_ser_2_s0
To | u_hdmi/u_serializer/lanes[3].u_oser
Launch Clk | serial_clk:[R]
Latch Clk | serial_clk:[F]

Data Arrival Path:

AT | DELAY | TYPE | RF | FANOUT | LOC | NODE
0.000 | 0.000 | | | | | active clock edge time
0.000 | 0.000 | | | | | serial_clk
4.133 | 4.133 | tCL | RR | 7 | PLL_R[1] | u_hdmi/u_clk/u_pll/CLKOUT0
6.804 | 2.671 | tNET | RR | 1 | R34C146[1][A] | u_hdmi/rstn_ser_2_s0/CLK
7.135 | 0.331 | tC2Q | RF | 4 | R34C146[1][A] | u_hdmi/rstn_ser_2_s0/Q
7.911 | 0.776 | tNET | FF | 1 | IOR24[A] | u_hdmi/u_serializer/lanes[3].u_oser/RESET

Data Required Path:

AT | DELAY | TYPE | RF | FANOUT | LOC | NODE
4.000 | 4.000 | | | | | active clock edge time
4.000 | 0.000 | | | | | serial_clk
8.133 | 4.133 | tCL | FF | 7 | PLL_R[1] | u_hdmi/u_clk/u_pll/CLKOUT0
8.133 | 0.000 | tNET | FF | 1 | IOR24[A] | u_hdmi/u_serializer/lanes[3].u_oser/FCLK
7.998 | -0.136 | tSu | | 1 | IOR24[A] | u_hdmi/u_serializer/lanes[3].u_oser

Path Statistics:

Clock Skew | -2.671
Setup Relationship | 4.000
Logic Level | 1
Arrival Clock Path Delay | cell: 0.000, 0.000%; route: 2.671, 100.000%
Arrival Data Path Delay | cell: 0.000, 0.000%; route: 0.776, 70.122%; tC2Q: 0.331, 29.878%
Required Clock Path Delay | cell: 0.000, 0.000%; route: 0.000, 0.000%

### Path2

Path Summary:

Slack | 0.094
Data Arrival Time | 7.903
Data Required Time | 7.998
From | u_hdmi/rstn_ser_2_s0
To | u_hdmi/u_serializer/lanes[0].u_oser
Launch Clk | serial_clk:[R]
Latch Clk | serial_clk:[F]

Data Arrival Path:

AT | DELAY | TYPE | RF | FANOUT | LOC | NODE
0.000 | 0.000 | | | | | active clock edge time
0.000 | 0.000 | | | | | serial_clk
4.133 | 4.133 | tCL | RR | 7 | PLL_R[1] | u_hdmi/u_clk/u_pll/CLKOUT0
6.804 | 2.671 | tNET | RR | 1 | R34C146[1][A] | u_hdmi/rstn_ser_2_s0/CLK
7.135 | 0.331 | tC2Q | RF | 4 | R34C146[1][A] | u_hdmi/rstn_ser_2_s0/Q
7.903 | 0.768 | tNET | FF | 1 | IOR26[A] | u_hdmi/u_serializer/lanes[0].u_oser/RESET

Data Required Path:

AT | DELAY | TYPE | RF | FANOUT | LOC | NODE
4.000 | 4.000 | | | | | active clock edge time
4.000 | 0.000 | | | | | serial_clk
8.133 | 4.133 | tCL | FF | 7 | PLL_R[1] | u_hdmi/u_clk/u_pll/CLKOUT0
8.133 | 0.000 | tNET | FF | 1 | IOR26[A] | u_hdmi/u_serializer/lanes[0].u_oser/FCLK
7.998 | -0.136 | tSu | | 1 | IOR26[A] | u_hdmi/u_serializer/lanes[0].u_oser

Path Statistics:

Clock Skew | -2.671
Setup Relationship | 4.000
Logic Level | 1
Arrival Clock Path Delay | cell: 0.000, 0.000%; route: 2.671, 100.000%
Arrival Data Path Delay | cell: 0.000, 0.000%; route: 0.768, 69.908%; tC2Q: 0.331, 30.092%
Required Clock Path Delay | cell: 0.000, 0.000%; route: 0.000, 0.000%

### Path3

Path Summary:

Slack | 0.165
Data Arrival Time | 7.832
Data Required Time | 7.998
From | u_hdmi/rstn_ser_2_s0
To | u_hdmi/u_serializer/lanes[1].u_oser
Launch Clk | serial_clk:[R]
Latch Clk | serial_clk:[F]

Data Arrival Path:

AT | DELAY | TYPE | RF | FANOUT | LOC | NODE
0.000 | 0.000 | | | | | active clock edge time
0.000 | 0.000 | | | | | serial_clk
4.133 | 4.133 | tCL | RR | 7 | PLL_R[1] | u_hdmi/u_clk/u_pll/CLKOUT0
6.804 | 2.671 | tNET | RR | 1 | R34C146[1][A] | u_hdmi/rstn_ser_2_s0/CLK
7.135 | 0.331 | tC2Q | RF | 4 | R34C146[1][A] | u_hdmi/rstn_ser_2_s0/Q
7.832 | 0.697 | tNET | FF | 1 | IOR22[A] | u_hdmi/u_serializer/lanes[1].u_oser/RESET

Data Required Path:

AT | DELAY | TYPE | RF | FANOUT | LOC | NODE
4.000 | 4.000 | | | | | active clock edge time
4.000 | 0.000 | | | | | serial_clk
8.133 | 4.133 | tCL | FF | 7 | PLL_R[1] | u_hdmi/u_clk/u_pll/CLKOUT0
8.133 | 0.000 | tNET | FF | 1 | IOR22[A] | u_hdmi/u_serializer/lanes[1].u_oser/FCLK
7.998 | -0.136 | tSu | | 1 | IOR22[A] | u_hdmi/u_serializer/lanes[1].u_oser

Path Statistics:

Clock Skew | -2.671
Setup Relationship | 4.000
Logic Level | 1
Arrival Clock Path Delay | cell: 0.000, 0.000%; route: 2.671, 100.000%
Arrival Data Path Delay | cell: 0.000, 0.000%; route: 0.697, 67.834%; tC2Q: 0.331, 32.166%
Required Clock Path Delay | cell: 0.000, 0.000%; route: 0.000, 0.000%

### Path4

Path Summary:

Slack | 0.170
Data Arrival Time | 7.828
Data Required Time | 7.998
From | u_hdmi/rstn_ser_2_s0
To | u_hdmi/u_serializer/lanes[2].u_oser
Launch Clk | serial_clk:[R]
Latch Clk | serial_clk:[F]

Data Arrival Path:

AT | DELAY | TYPE | RF | FANOUT | LOC | NODE
0.000 | 0.000 | | | | | active clock edge time
0.000 | 0.000 | | | | | serial_clk
4.133 | 4.133 | tCL | RR | 7 | PLL_R[1] | u_hdmi/u_clk/u_pll/CLKOUT0
6.804 | 2.671 | tNET | RR | 1 | R34C146[1][A] | u_hdmi/rstn_ser_2_s0/CLK
7.135 | 0.331 | tC2Q | RF | 4 | R34C146[1][A] | u_hdmi/rstn_ser_2_s0/Q
7.828 | 0.693 | tNET | FF | 1 | IOR39[A] | u_hdmi/u_serializer/lanes[2].u_oser/RESET

Data Required Path:

AT | DELAY | TYPE | RF | FANOUT | LOC | NODE
4.000 | 4.000 | | | | | active clock edge time
4.000 | 0.000 | | | | | serial_clk
8.133 | 4.133 | tCL | FF | 7 | PLL_R[1] | u_hdmi/u_clk/u_pll/CLKOUT0
8.133 | 0.000 | tNET | FF | 1 | IOR39[A] | u_hdmi/u_serializer/lanes[2].u_oser/FCLK
7.998 | -0.136 | tSu | | 1 | IOR39[A] | u_hdmi/u_serializer/lanes[2].u_oser

Path Statistics:

Clock Skew | -2.671
Setup Relationship | 4.000
Logic Level | 1
Arrival Clock Path Delay | cell: 0.000, 0.000%; route: 2.671, 100.000%
Arrival Data Path Delay | cell: 0.000, 0.000%; route: 0.693, 67.692%; tC2Q: 0.331, 32.308%
Required Clock Path Delay | cell: 0.000, 0.000%; route: 0.000, 0.000%

### Path5

Path Summary:

Slack | 4.085
Data Arrival Time | 7.911
Data Required Time | 11.996
From | u_hdmi/rstn_ser_2_s0
To | u_hdmi/u_serializer/lanes[3].u_oser
Launch Clk | serial_clk:[R]
Latch Clk | serial_clk:[R]

Data Arrival Path:

AT | DELAY | TYPE | RF | FANOUT | LOC | NODE
0.000 | 0.000 | | | | | active clock edge time
0.000 | 0.000 | | | | | serial_clk
4.133 | 4.133 | tCL | RR | 7 | PLL_R[1] | u_hdmi/u_clk/u_pll/CLKOUT0
6.804 | 2.671 | tNET | RR | 1 | R34C146[1][A] | u_hdmi/rstn_ser_2_s0/CLK
7.135 | 0.331 | tC2Q | RF | 4 | R34C146[1][A] | u_hdmi/rstn_ser_2_s0/Q
7.911 | 0.776 | tNET | FF | 1 | IOR24[A] | u_hdmi/u_serializer/lanes[3].u_oser/RESET

Data Required Path:

AT | DELAY | TYPE | RF | FANOUT | LOC | NODE
8.000 | 8.000 | | | | | active clock edge time
8.000 | 0.000 | | | | | serial_clk
12.133 | 4.133 | tCL | RR | 7 | PLL_R[1] | u_hdmi/u_clk/u_pll/CLKOUT0
12.133 | 0.000 | tNET | RR | 1 | IOR24[A] | u_hdmi/u_serializer/lanes[3].u_oser/FCLK
11.996 | -0.138 | tSu | | 1 | IOR24[A] | u_hdmi/u_serializer/lanes[3].u_oser

Path Statistics:

Clock Skew | -2.671
Setup Relationship | 8.000
Logic Level | 1
Arrival Clock Path Delay | cell: 0.000, 0.000%; route: 2.671, 100.000%
Arrival Data Path Delay | cell: 0.000, 0.000%; route: 0.776, 70.122%; tC2Q: 0.331, 29.878%
Required Clock Path Delay | cell: 0.000, 0.000%; route: 0.000, 0.000%

### Path6

Path Summary:

Slack | 4.092
Data Arrival Time | 7.903
Data Required Time | 11.996
From | u_hdmi/rstn_ser_2_s0
To | u_hdmi/u_serializer/lanes[0].u_oser
Launch Clk | serial_clk:[R]
Latch Clk | serial_clk:[R]

Data Arrival Path:

AT | DELAY | TYPE | RF | FANOUT | LOC | NODE
0.000 | 0.000 | | | | | active clock edge time
0.000 | 0.000 | | | | | serial_clk
4.133 | 4.133 | tCL | RR | 7 | PLL_R[1] | u_hdmi/u_clk/u_pll/CLKOUT0
6.804 | 2.671 | tNET | RR | 1 | R34C146[1][A] | u_hdmi/rstn_ser_2_s0/CLK
7.135 | 0.331 | tC2Q | RF | 4 | R34C146[1][A] | u_hdmi/rstn_ser_2_s0/Q
7.903 | 0.768 | tNET | FF | 1 | IOR26[A] | u_hdmi/u_serializer/lanes[0].u_oser/RESET

Data Required Path:

AT | DELAY | TYPE | RF | FANOUT | LOC | NODE
8.000 | 8.000 | | | | | active clock edge time
8.000 | 0.000 | | | | | serial_clk
12.133 | 4.133 | tCL | RR | 7 | PLL_R[1] | u_hdmi/u_clk/u_pll/CLKOUT0
12.133 | 0.000 | tNET | RR | 1 | IOR26[A] | u_hdmi/u_serializer/lanes[0].u_oser/FCLK
11.996 | -0.138 | tSu | | 1 | IOR26[A] | u_hdmi/u_serializer/lanes[0].u_oser

Path Statistics:

Clock Skew | -2.671
Setup Relationship | 8.000
Logic Level | 1
Arrival Clock Path Delay | cell: 0.000, 0.000%; route: 2.671, 100.000%
Arrival Data Path Delay | cell: 0.000, 0.000%; route: 0.768, 69.908%; tC2Q: 0.331, 30.092%
Required Clock Path Delay | cell: 0.000, 0.000%; route: 0.000, 0.000%

### Path7

Path Summary:

Slack | 4.163
Data Arrival Time | 7.832
Data Required Time | 11.996
From | u_hdmi/rstn_ser_2_s0
To | u_hdmi/u_serializer/lanes[1].u_oser
Launch Clk | serial_clk:[R]
Latch Clk | serial_clk:[R]

Data Arrival Path:

AT | DELAY | TYPE | RF | FANOUT | LOC | NODE
0.000 | 0.000 | | | | | active clock edge time
0.000 | 0.000 | | | | | serial_clk
4.133 | 4.133 | tCL | RR | 7 | PLL_R[1] | u_hdmi/u_clk/u_pll/CLKOUT0
6.804 | 2.671 | tNET | RR | 1 | R34C146[1][A] | u_hdmi/rstn_ser_2_s0/CLK
7.135 | 0.331 | tC2Q | RF | 4 | R34C146[1][A] | u_hdmi/rstn_ser_2_s0/Q
7.832 | 0.697 | tNET | FF | 1 | IOR22[A] | u_hdmi/u_serializer/lanes[1].u_oser/RESET

Data Required Path:

AT | DELAY | TYPE | RF | FANOUT | LOC | NODE
8.000 | 8.000 | | | | | active clock edge time
8.000 | 0.000 | | | | | serial_clk
12.133 | 4.133 | tCL | RR | 7 | PLL_R[1] | u_hdmi/u_clk/u_pll/CLKOUT0
12.133 | 0.000 | tNET | RR | 1 | IOR22[A] | u_hdmi/u_serializer/lanes[1].u_oser/FCLK
11.996 | -0.138 | tSu | | 1 | IOR22[A] | u_hdmi/u_serializer/lanes[1].u_oser

Path Statistics:

Clock Skew | -2.671
Setup Relationship | 8.000
Logic Level | 1
Arrival Clock Path Delay | cell: 0.000, 0.000%; route: 2.671, 100.000%
Arrival Data Path Delay | cell: 0.000, 0.000%; route: 0.697, 67.834%; tC2Q: 0.331, 32.166%
Required Clock Path Delay | cell: 0.000, 0.000%; route: 0.000, 0.000%

### Path8

Path Summary:

Slack | 4.168
Data Arrival Time | 7.828
Data Required Time | 11.996
From | u_hdmi/rstn_ser_2_s0
To | u_hdmi/u_serializer/lanes[2].u_oser
Launch Clk | serial_clk:[R]
Latch Clk | serial_clk:[R]

Data Arrival Path:

AT | DELAY | TYPE | RF | FANOUT | LOC | NODE
0.000 | 0.000 | | | | | active clock edge time
0.000 | 0.000 | | | | | serial_clk
4.133 | 4.133 | tCL | RR | 7 | PLL_R[1] | u_hdmi/u_clk/u_pll/CLKOUT0
6.804 | 2.671 | tNET | RR | 1 | R34C146[1][A] | u_hdmi/rstn_ser_2_s0/CLK
7.135 | 0.331 | tC2Q | RF | 4 | R34C146[1][A] | u_hdmi/rstn_ser_2_s0/Q
7.828 | 0.693 | tNET | FF | 1 | IOR39[A] | u_hdmi/u_serializer/lanes[2].u_oser/RESET

Data Required Path:

AT | DELAY | TYPE | RF | FANOUT | LOC | NODE
8.000 | 8.000 | | | | | active clock edge time
8.000 | 0.000 | | | | | serial_clk
12.133 | 4.133 | tCL | RR | 7 | PLL_R[1] | u_hdmi/u_clk/u_pll/CLKOUT0
12.133 | 0.000 | tNET | RR | 1 | IOR39[A] | u_hdmi/u_serializer/lanes[2].u_oser/FCLK
11.996 | -0.138 | tSu | | 1 | IOR39[A] | u_hdmi/u_serializer/lanes[2].u_oser

Path Statistics:

Clock Skew | -2.671
Setup Relationship | 8.000
Logic Level | 1
Arrival Clock Path Delay | cell: 0.000, 0.000%; route: 2.671, 100.000%
Arrival Data Path Delay | cell: 0.000, 0.000%; route: 0.693, 67.692%; tC2Q: 0.331, 32.308%
Required Clock Path Delay | cell: 0.000, 0.000%; route: 0.000, 0.000%

### Path9

Path Summary:

Slack | 5.931
Data Arrival Time | 39.911
Data Required Time | 45.842
From | u_hdmi/rstn_ser_2_s0
To | u_hdmi/u_serializer/lanes[3].u_oser
Launch Clk | serial_clk:[R]
Latch Clk | pixel_clk:[R]

Data Arrival Path:

AT | DELAY | TYPE | RF | FANOUT | LOC | NODE
32.000 | 32.000 | | | | | active clock edge time
32.000 | 0.000 | | | | | serial_clk
36.133 | 4.133 | tCL | RR | 7 | PLL_R[1] | u_hdmi/u_clk/u_pll/CLKOUT0
38.804 | 2.671 | tNET | RR | 1 | R34C146[1][A] | u_hdmi/rstn_ser_2_s0/CLK
39.135 | 0.331 | tC2Q | RF | 4 | R34C146[1][A] | u_hdmi/rstn_ser_2_s0/Q
39.911 | 0.776 | tNET | FF | 1 | IOR24[A] | u_hdmi/u_serializer/lanes[3].u_oser/RESET

Data Required Path:

AT | DELAY | TYPE | RF | FANOUT | LOC | NODE
40.000 | 40.000 | | | | | active clock edge time
40.000 | 0.000 | | | | | pixel_clk
44.133 | 4.133 | tCL | RR | 340 | PLL_R[1] | u_hdmi/u_clk/u_pll/CLKOUT1
46.014 | 1.881 | tNET | RR | 1 | IOR24[A] | u_hdmi/u_serializer/lanes[3].u_oser/PCLK
45.979 | -0.035 | tUnc
45.842 | -0.138 | tSu | | 1 | IOR24[A] | u_hdmi/u_serializer/lanes[3].u_oser

Path Statistics:

Clock Skew | -0.790
Setup Relationship | 8.000
Logic Level | 1
Arrival Clock Path Delay | cell: 0.000, 0.000%; route: 2.671, 100.000%
Arrival Data Path Delay | cell: 0.000, 0.000%; route: 0.776, 70.122%; tC2Q: 0.331, 29.878%
Required Clock Path Delay | cell: 0.000, 0.000%; route: 1.881, 100.000%

### Path10

Path Summary:

Slack | 5.938
Data Arrival Time | 39.903
Data Required Time | 45.842
From | u_hdmi/rstn_ser_2_s0
To | u_hdmi/u_serializer/lanes[0].u_oser
Launch Clk | serial_clk:[R]
Latch Clk | pixel_clk:[R]

Data Arrival Path:

AT | DELAY | TYPE | RF | FANOUT | LOC | NODE
32.000 | 32.000 | | | | | active clock edge time
32.000 | 0.000 | | | | | serial_clk
36.133 | 4.133 | tCL | RR | 7 | PLL_R[1] | u_hdmi/u_clk/u_pll/CLKOUT0
38.804 | 2.671 | tNET | RR | 1 | R34C146[1][A] | u_hdmi/rstn_ser_2_s0/CLK
39.135 | 0.331 | tC2Q | RF | 4 | R34C146[1][A] | u_hdmi/rstn_ser_2_s0/Q
39.903 | 0.768 | tNET | FF | 1 | IOR26[A] | u_hdmi/u_serializer/lanes[0].u_oser/RESET

Data Required Path:

AT | DELAY | TYPE | RF | FANOUT | LOC | NODE
40.000 | 40.000 | | | | | active clock edge time
40.000 | 0.000 | | | | | pixel_clk
44.133 | 4.133 | tCL | RR | 340 | PLL_R[1] | u_hdmi/u_clk/u_pll/CLKOUT1
46.014 | 1.881 | tNET | RR | 1 | IOR26[A] | u_hdmi/u_serializer/lanes[0].u_oser/PCLK
45.979 | -0.035 | tUnc
45.842 | -0.138 | tSu | | 1 | IOR26[A] | u_hdmi/u_serializer/lanes[0].u_oser

Path Statistics:

Clock Skew | -0.790
Setup Relationship | 8.000
Logic Level | 1
Arrival Clock Path Delay | cell: 0.000, 0.000%; route: 2.671, 100.000%
Arrival Data Path Delay | cell: 0.000, 0.000%; route: 0.768, 69.908%; tC2Q: 0.331, 30.092%
Required Clock Path Delay | cell: 0.000, 0.000%; route: 1.881, 100.000%

### Path11

Path Summary:

Slack | 6.009
Data Arrival Time | 39.832
Data Required Time | 45.842
From | u_hdmi/rstn_ser_2_s0
To | u_hdmi/u_serializer/lanes[1].u_oser
Launch Clk | serial_clk:[R]
Latch Clk | pixel_clk:[R]

Data Arrival Path:

AT | DELAY | TYPE | RF | FANOUT | LOC | NODE
32.000 | 32.000 | | | | | active clock edge time
32.000 | 0.000 | | | | | serial_clk
36.133 | 4.133 | tCL | RR | 7 | PLL_R[1] | u_hdmi/u_clk/u_pll/CLKOUT0
38.804 | 2.671 | tNET | RR | 1 | R34C146[1][A] | u_hdmi/rstn_ser_2_s0/CLK
39.135 | 0.331 | tC2Q | RF | 4 | R34C146[1][A] | u_hdmi/rstn_ser_2_s0/Q
39.832 | 0.697 | tNET | FF | 1 | IOR22[A] | u_hdmi/u_serializer/lanes[1].u_oser/RESET

Data Required Path:

AT | DELAY | TYPE | RF | FANOUT | LOC | NODE
40.000 | 40.000 | | | | | active clock edge time
40.000 | 0.000 | | | | | pixel_clk
44.133 | 4.133 | tCL | RR | 340 | PLL_R[1] | u_hdmi/u_clk/u_pll/CLKOUT1
46.014 | 1.881 | tNET | RR | 1 | IOR22[A] | u_hdmi/u_serializer/lanes[1].u_oser/PCLK
45.979 | -0.035 | tUnc
45.842 | -0.138 | tSu | | 1 | IOR22[A] | u_hdmi/u_serializer/lanes[1].u_oser

Path Statistics:

Clock Skew | -0.790
Setup Relationship | 8.000
Logic Level | 1
Arrival Clock Path Delay | cell: 0.000, 0.000%; route: 2.671, 100.000%
Arrival Data Path Delay | cell: 0.000, 0.000%; route: 0.697, 67.834%; tC2Q: 0.331, 32.166%
Required Clock Path Delay | cell: 0.000, 0.000%; route: 1.881, 100.000%

### Path12

Path Summary:

Slack | 6.014
Data Arrival Time | 39.828
Data Required Time | 45.842
From | u_hdmi/rstn_ser_2_s0
To | u_hdmi/u_serializer/lanes[2].u_oser
Launch Clk | serial_clk:[R]
Latch Clk | pixel_clk:[R]

Data Arrival Path:

AT | DELAY | TYPE | RF | FANOUT | LOC | NODE
32.000 | 32.000 | | | | | active clock edge time
32.000 | 0.000 | | | | | serial_clk
36.133 | 4.133 | tCL | RR | 7 | PLL_R[1] | u_hdmi/u_clk/u_pll/CLKOUT0
38.804 | 2.671 | tNET | RR | 1 | R34C146[1][A] | u_hdmi/rstn_ser_2_s0/CLK
39.135 | 0.331 | tC2Q | RF | 4 | R34C146[1][A] | u_hdmi/rstn_ser_2_s0/Q
39.828 | 0.693 | tNET | FF | 1 | IOR39[A] | u_hdmi/u_serializer/lanes[2].u_oser/RESET

Data Required Path:

AT | DELAY | TYPE | RF | FANOUT | LOC | NODE
40.000 | 40.000 | | | | | active clock edge time
40.000 | 0.000 | | | | | pixel_clk
44.133 | 4.133 | tCL | RR | 340 | PLL_R[1] | u_hdmi/u_clk/u_pll/CLKOUT1
46.014 | 1.881 | tNET | RR | 1 | IOR39[A] | u_hdmi/u_serializer/lanes[2].u_oser/PCLK
45.979 | -0.035 | tUnc
45.842 | -0.138 | tSu | | 1 | IOR39[A] | u_hdmi/u_serializer/lanes[2].u_oser

Path Statistics:

Clock Skew | -0.790
Setup Relationship | 8.000
Logic Level | 1
Arrival Clock Path Delay | cell: 0.000, 0.000%; route: 2.671, 100.000%
Arrival Data Path Delay | cell: 0.000, 0.000%; route: 0.693, 67.692%; tC2Q: 0.331, 32.308%
Required Clock Path Delay | cell: 0.000, 0.000%; route: 1.881, 100.000%

### Removal Analysis Report

#### Report Command:report_timing -removal -max_paths 25 -max_common_paths 1

### Path1

Path Summary:

Slack | 0.494
Data Arrival Time | 43.455
Data Required Time | 42.961
From | u_hdmi/rstn_ser_2_s0
To | u_hdmi/u_serializer/lanes[1].u_oser
Launch Clk | serial_clk:[R]
Latch Clk | pixel_clk:[R]

Data Arrival Path:

AT | DELAY | TYPE | RF | FANOUT | LOC | NODE
40.000 | 40.000 | | | | | active clock edge time
40.000 | 0.000 | | | | | serial_clk
42.186 | 2.186 | tCL | RR | 7 | PLL_R[1] | u_hdmi/u_clk/u_pll/CLKOUT0
43.113 | 0.927 | tNET | RR | 1 | R34C146[1][A] | u_hdmi/rstn_ser_2_s0/CLK
43.243 | 0.130 | tC2Q | RR | 4 | R34C146[1][A] | u_hdmi/rstn_ser_2_s0/Q
43.455 | 0.212 | tNET | RR | 1 | IOR22[A] | u_hdmi/u_serializer/lanes[1].u_oser/RESET

Data Required Path:

AT | DELAY | TYPE | RF | FANOUT | LOC | NODE
40.000 | 40.000 | | | | | active clock edge time
40.000 | 0.000 | | | | | pixel_clk
42.186 | 2.186 | tCL | RR | 340 | PLL_R[1] | u_hdmi/u_clk/u_pll/CLKOUT1
42.788 | 0.602 | tNET | RR | 1 | IOR22[A] | u_hdmi/u_serializer/lanes[1].u_oser/PCLK
42.823 | 0.035 | tUnc
42.961 | 0.138 | tHld | | 1 | IOR22[A] | u_hdmi/u_serializer/lanes[1].u_oser

Path Statistics:

Clock Skew | -0.325
Hold Relationship | 0.000
Logic Level | 1
Arrival Clock Path Delay | cell: 0.000, 0.000%; route: 0.927, 100.000%
Arrival Data Path Delay | cell: 0.000, 0.000%; route: 0.212, 62.105%; tC2Q: 0.130, 37.895%
Required Clock Path Delay | cell: 0.000, 0.000%; route: 0.602, 100.000%

### Path2

Path Summary:

Slack | 0.498
Data Arrival Time | 43.459
Data Required Time | 42.961
From | u_hdmi/rstn_ser_2_s0
To | u_hdmi/u_serializer/lanes[2].u_oser
Launch Clk | serial_clk:[R]
Latch Clk | pixel_clk:[R]

Data Arrival Path:

AT | DELAY | TYPE | RF | FANOUT | LOC | NODE
40.000 | 40.000 | | | | | active clock edge time
40.000 | 0.000 | | | | | serial_clk
42.186 | 2.186 | tCL | RR | 7 | PLL_R[1] | u_hdmi/u_clk/u_pll/CLKOUT0
43.113 | 0.927 | tNET | RR | 1 | R34C146[1][A] | u_hdmi/rstn_ser_2_s0/CLK
43.243 | 0.130 | tC2Q | RR | 4 | R34C146[1][A] | u_hdmi/rstn_ser_2_s0/Q
43.459 | 0.216 | tNET | RR | 1 | IOR39[A] | u_hdmi/u_serializer/lanes[2].u_oser/RESET

Data Required Path:

AT | DELAY | TYPE | RF | FANOUT | LOC | NODE
40.000 | 40.000 | | | | | active clock edge time
40.000 | 0.000 | | | | | pixel_clk
42.186 | 2.186 | tCL | RR | 340 | PLL_R[1] | u_hdmi/u_clk/u_pll/CLKOUT1
42.788 | 0.602 | tNET | RR | 1 | IOR39[A] | u_hdmi/u_serializer/lanes[2].u_oser/PCLK
42.823 | 0.035 | tUnc
42.961 | 0.138 | tHld | | 1 | IOR39[A] | u_hdmi/u_serializer/lanes[2].u_oser

Path Statistics:

Clock Skew | -0.325
Hold Relationship | 0.000
Logic Level | 1
Arrival Clock Path Delay | cell: 0.000, 0.000%; route: 0.927, 100.000%
Arrival Data Path Delay | cell: 0.000, 0.000%; route: 0.216, 62.500%; tC2Q: 0.130, 37.500%
Required Clock Path Delay | cell: 0.000, 0.000%; route: 0.602, 100.000%

### Path3

Path Summary:

Slack | 0.556
Data Arrival Time | 43.517
Data Required Time | 42.961
From | u_hdmi/rstn_ser_2_s0
To | u_hdmi/u_serializer/lanes[0].u_oser
Launch Clk | serial_clk:[R]
Latch Clk | pixel_clk:[R]

Data Arrival Path:

AT | DELAY | TYPE | RF | FANOUT | LOC | NODE
40.000 | 40.000 | | | | | active clock edge time
40.000 | 0.000 | | | | | serial_clk
42.186 | 2.186 | tCL | RR | 7 | PLL_R[1] | u_hdmi/u_clk/u_pll/CLKOUT0
43.113 | 0.927 | tNET | RR | 1 | R34C146[1][A] | u_hdmi/rstn_ser_2_s0/CLK
43.243 | 0.130 | tC2Q | RR | 4 | R34C146[1][A] | u_hdmi/rstn_ser_2_s0/Q
43.517 | 0.274 | tNET | RR | 1 | IOR26[A] | u_hdmi/u_serializer/lanes[0].u_oser/RESET

Data Required Path:

AT | DELAY | TYPE | RF | FANOUT | LOC | NODE
40.000 | 40.000 | | | | | active clock edge time
40.000 | 0.000 | | | | | pixel_clk
42.186 | 2.186 | tCL | RR | 340 | PLL_R[1] | u_hdmi/u_clk/u_pll/CLKOUT1
42.788 | 0.602 | tNET | RR | 1 | IOR26[A] | u_hdmi/u_serializer/lanes[0].u_oser/PCLK
42.823 | 0.035 | tUnc
42.961 | 0.138 | tHld | | 1 | IOR26[A] | u_hdmi/u_serializer/lanes[0].u_oser

Path Statistics:

Clock Skew | -0.325
Hold Relationship | 0.000
Logic Level | 1
Arrival Clock Path Delay | cell: 0.000, 0.000%; route: 0.927, 100.000%
Arrival Data Path Delay | cell: 0.000, 0.000%; route: 0.274, 67.929%; tC2Q: 0.130, 32.071%
Required Clock Path Delay | cell: 0.000, 0.000%; route: 0.602, 100.000%

### Path4

Path Summary:

Slack | 0.645
Data Arrival Time | 43.605
Data Required Time | 42.961
From | u_hdmi/rstn_ser_2_s0
To | u_hdmi/u_serializer/lanes[3].u_oser
Launch Clk | serial_clk:[R]
Latch Clk | pixel_clk:[R]

Data Arrival Path:

AT | DELAY | TYPE | RF | FANOUT | LOC | NODE
40.000 | 40.000 | | | | | active clock edge time
40.000 | 0.000 | | | | | serial_clk
42.186 | 2.186 | tCL | RR | 7 | PLL_R[1] | u_hdmi/u_clk/u_pll/CLKOUT0
43.113 | 0.927 | tNET | RR | 1 | R34C146[1][A] | u_hdmi/rstn_ser_2_s0/CLK
43.243 | 0.130 | tC2Q | RR | 4 | R34C146[1][A] | u_hdmi/rstn_ser_2_s0/Q
43.605 | 0.363 | tNET | RR | 1 | IOR24[A] | u_hdmi/u_serializer/lanes[3].u_oser/RESET

Data Required Path:

AT | DELAY | TYPE | RF | FANOUT | LOC | NODE
40.000 | 40.000 | | | | | active clock edge time
40.000 | 0.000 | | | | | pixel_clk
42.186 | 2.186 | tCL | RR | 340 | PLL_R[1] | u_hdmi/u_clk/u_pll/CLKOUT1
42.788 | 0.602 | tNET | RR | 1 | IOR24[A] | u_hdmi/u_serializer/lanes[3].u_oser/PCLK
42.823 | 0.035 | tUnc
42.961 | 0.138 | tHld | | 1 | IOR24[A] | u_hdmi/u_serializer/lanes[3].u_oser

Path Statistics:

Clock Skew | -0.325
Hold Relationship | 0.000
Logic Level | 1
Arrival Clock Path Delay | cell: 0.000, 0.000%; route: 0.927, 100.000%
Arrival Data Path Delay | cell: 0.000, 0.000%; route: 0.363, 73.675%; tC2Q: 0.130, 26.325%
Required Clock Path Delay | cell: 0.000, 0.000%; route: 0.602, 100.000%

### Path5

Path Summary:

Slack | 1.131
Data Arrival Time | 3.455
Data Required Time | 2.324
From | u_hdmi/rstn_ser_2_s0
To | u_hdmi/u_serializer/lanes[1].u_oser
Launch Clk | serial_clk:[R]
Latch Clk | serial_clk:[R]

Data Arrival Path:

AT | DELAY | TYPE | RF | FANOUT | LOC | NODE
0.000 | 0.000 | | | | | active clock edge time
0.000 | 0.000 | | | | | serial_clk
2.186 | 2.186 | tCL | RR | 7 | PLL_R[1] | u_hdmi/u_clk/u_pll/CLKOUT0
3.113 | 0.927 | tNET | RR | 1 | R34C146[1][A] | u_hdmi/rstn_ser_2_s0/CLK
3.243 | 0.130 | tC2Q | RR | 4 | R34C146[1][A] | u_hdmi/rstn_ser_2_s0/Q
3.455 | 0.212 | tNET | RR | 1 | IOR22[A] | u_hdmi/u_serializer/lanes[1].u_oser/RESET

Data Required Path:

AT | DELAY | TYPE | RF | FANOUT | LOC | NODE
0.000 | 0.000 | | | | | active clock edge time
0.000 | 0.000 | | | | | serial_clk
2.186 | 2.186 | tCL | RR | 7 | PLL_R[1] | u_hdmi/u_clk/u_pll/CLKOUT0
2.186 | 0.000 | tNET | RR | 1 | IOR22[A] | u_hdmi/u_serializer/lanes[1].u_oser/FCLK
2.324 | 0.138 | tHld | | 1 | IOR22[A] | u_hdmi/u_serializer/lanes[1].u_oser

Path Statistics:

Clock Skew | -0.927
Hold Relationship | 0.000
Logic Level | 1
Arrival Clock Path Delay | cell: 0.000, 0.000%; route: 0.927, 100.000%
Arrival Data Path Delay | cell: 0.000, 0.000%; route: 0.212, 62.105%; tC2Q: 0.130, 37.895%
Required Clock Path Delay | cell: 0.000, 0.000%; route: 0.000, 0.000%

### Path6

Path Summary:

Slack | 1.135
Data Arrival Time | 3.459
Data Required Time | 2.324
From | u_hdmi/rstn_ser_2_s0
To | u_hdmi/u_serializer/lanes[2].u_oser
Launch Clk | serial_clk:[R]
Latch Clk | serial_clk:[R]

Data Arrival Path:

AT | DELAY | TYPE | RF | FANOUT | LOC | NODE
0.000 | 0.000 | | | | | active clock edge time
0.000 | 0.000 | | | | | serial_clk
2.186 | 2.186 | tCL | RR | 7 | PLL_R[1] | u_hdmi/u_clk/u_pll/CLKOUT0
3.113 | 0.927 | tNET | RR | 1 | R34C146[1][A] | u_hdmi/rstn_ser_2_s0/CLK
3.243 | 0.130 | tC2Q | RR | 4 | R34C146[1][A] | u_hdmi/rstn_ser_2_s0/Q
3.459 | 0.216 | tNET | RR | 1 | IOR39[A] | u_hdmi/u_serializer/lanes[2].u_oser/RESET

Data Required Path:

AT | DELAY | TYPE | RF | FANOUT | LOC | NODE
0.000 | 0.000 | | | | | active clock edge time
0.000 | 0.000 | | | | | serial_clk
2.186 | 2.186 | tCL | RR | 7 | PLL_R[1] | u_hdmi/u_clk/u_pll/CLKOUT0
2.186 | 0.000 | tNET | RR | 1 | IOR39[A] | u_hdmi/u_serializer/lanes[2].u_oser/FCLK
2.324 | 0.138 | tHld | | 1 | IOR39[A] | u_hdmi/u_serializer/lanes[2].u_oser

Path Statistics:

Clock Skew | -0.927
Hold Relationship | 0.000
Logic Level | 1
Arrival Clock Path Delay | cell: 0.000, 0.000%; route: 0.927, 100.000%
Arrival Data Path Delay | cell: 0.000, 0.000%; route: 0.216, 62.500%; tC2Q: 0.130, 37.500%
Required Clock Path Delay | cell: 0.000, 0.000%; route: 0.000, 0.000%

### Path7

Path Summary:

Slack | 1.193
Data Arrival Time | 3.517
Data Required Time | 2.324
From | u_hdmi/rstn_ser_2_s0
To | u_hdmi/u_serializer/lanes[0].u_oser
Launch Clk | serial_clk:[R]
Latch Clk | serial_clk:[R]

Data Arrival Path:

AT | DELAY | TYPE | RF | FANOUT | LOC | NODE
0.000 | 0.000 | | | | | active clock edge time
0.000 | 0.000 | | | | | serial_clk
2.186 | 2.186 | tCL | RR | 7 | PLL_R[1] | u_hdmi/u_clk/u_pll/CLKOUT0
3.113 | 0.927 | tNET | RR | 1 | R34C146[1][A] | u_hdmi/rstn_ser_2_s0/CLK
3.243 | 0.130 | tC2Q | RR | 4 | R34C146[1][A] | u_hdmi/rstn_ser_2_s0/Q
3.517 | 0.274 | tNET | RR | 1 | IOR26[A] | u_hdmi/u_serializer/lanes[0].u_oser/RESET

Data Required Path:

AT | DELAY | TYPE | RF | FANOUT | LOC | NODE
0.000 | 0.000 | | | | | active clock edge time
0.000 | 0.000 | | | | | serial_clk
2.186 | 2.186 | tCL | RR | 7 | PLL_R[1] | u_hdmi/u_clk/u_pll/CLKOUT0
2.186 | 0.000 | tNET | RR | 1 | IOR26[A] | u_hdmi/u_serializer/lanes[0].u_oser/FCLK
2.324 | 0.138 | tHld | | 1 | IOR26[A] | u_hdmi/u_serializer/lanes[0].u_oser

Path Statistics:

Clock Skew | -0.927
Hold Relationship | 0.000
Logic Level | 1
Arrival Clock Path Delay | cell: 0.000, 0.000%; route: 0.927, 100.000%
Arrival Data Path Delay | cell: 0.000, 0.000%; route: 0.274, 67.929%; tC2Q: 0.130, 32.071%
Required Clock Path Delay | cell: 0.000, 0.000%; route: 0.000, 0.000%

### Path8

Path Summary:

Slack | 1.282
Data Arrival Time | 3.605
Data Required Time | 2.324
From | u_hdmi/rstn_ser_2_s0
To | u_hdmi/u_serializer/lanes[3].u_oser
Launch Clk | serial_clk:[R]
Latch Clk | serial_clk:[R]

Data Arrival Path:

AT | DELAY | TYPE | RF | FANOUT | LOC | NODE
0.000 | 0.000 | | | | | active clock edge time
0.000 | 0.000 | | | | | serial_clk
2.186 | 2.186 | tCL | RR | 7 | PLL_R[1] | u_hdmi/u_clk/u_pll/CLKOUT0
3.113 | 0.927 | tNET | RR | 1 | R34C146[1][A] | u_hdmi/rstn_ser_2_s0/CLK
3.243 | 0.130 | tC2Q | RR | 4 | R34C146[1][A] | u_hdmi/rstn_ser_2_s0/Q
3.605 | 0.363 | tNET | RR | 1 | IOR24[A] | u_hdmi/u_serializer/lanes[3].u_oser/RESET

Data Required Path:

AT | DELAY | TYPE | RF | FANOUT | LOC | NODE
0.000 | 0.000 | | | | | active clock edge time
0.000 | 0.000 | | | | | serial_clk
2.186 | 2.186 | tCL | RR | 7 | PLL_R[1] | u_hdmi/u_clk/u_pll/CLKOUT0
2.186 | 0.000 | tNET | RR | 1 | IOR24[A] | u_hdmi/u_serializer/lanes[3].u_oser/FCLK
2.324 | 0.138 | tHld | | 1 | IOR24[A] | u_hdmi/u_serializer/lanes[3].u_oser

Path Statistics:

Clock Skew | -0.927
Hold Relationship | 0.000
Logic Level | 1
Arrival Clock Path Delay | cell: 0.000, 0.000%; route: 0.927, 100.000%
Arrival Data Path Delay | cell: 0.000, 0.000%; route: 0.363, 73.675%; tC2Q: 0.130, 26.325%
Required Clock Path Delay | cell: 0.000, 0.000%; route: 0.000, 0.000%

### Path9

Path Summary:

Slack | 5.133
Data Arrival Time | 3.455
Data Required Time | -1.678
From | u_hdmi/rstn_ser_2_s0
To | u_hdmi/u_serializer/lanes[1].u_oser
Launch Clk | serial_clk:[R]
Latch Clk | serial_clk:[F]

Data Arrival Path:

AT | DELAY | TYPE | RF | FANOUT | LOC | NODE
0.000 | 0.000 | | | | | active clock edge time
0.000 | 0.000 | | | | | serial_clk
2.186 | 2.186 | tCL | RR | 7 | PLL_R[1] | u_hdmi/u_clk/u_pll/CLKOUT0
3.113 | 0.927 | tNET | RR | 1 | R34C146[1][A] | u_hdmi/rstn_ser_2_s0/CLK
3.243 | 0.130 | tC2Q | RR | 4 | R34C146[1][A] | u_hdmi/rstn_ser_2_s0/Q
3.455 | 0.212 | tNET | RR | 1 | IOR22[A] | u_hdmi/u_serializer/lanes[1].u_oser/RESET

Data Required Path:

AT | DELAY | TYPE | RF | FANOUT | LOC | NODE
-4.000 | -4.000 | | | | | active clock edge time
-4.000 | 0.000 | | | | | serial_clk
-1.814 | 2.186 | tCL | FF | 7 | PLL_R[1] | u_hdmi/u_clk/u_pll/CLKOUT0
-1.814 | 0.000 | tNET | FF | 1 | IOR22[A] | u_hdmi/u_serializer/lanes[1].u_oser/FCLK
-1.678 | 0.136 | tHld | | 1 | IOR22[A] | u_hdmi/u_serializer/lanes[1].u_oser

Path Statistics:

Clock Skew | -0.927
Hold Relationship | -4.000
Logic Level | 1
Arrival Clock Path Delay | cell: 0.000, 0.000%; route: 0.927, 100.000%
Arrival Data Path Delay | cell: 0.000, 0.000%; route: 0.212, 62.105%; tC2Q: 0.130, 37.895%
Required Clock Path Delay | cell: 0.000, 0.000%; route: 0.000, 0.000%

### Path10

Path Summary:

Slack | 5.137
Data Arrival Time | 3.459
Data Required Time | -1.678
From | u_hdmi/rstn_ser_2_s0
To | u_hdmi/u_serializer/lanes[2].u_oser
Launch Clk | serial_clk:[R]
Latch Clk | serial_clk:[F]

Data Arrival Path:

AT | DELAY | TYPE | RF | FANOUT | LOC | NODE
0.000 | 0.000 | | | | | active clock edge time
0.000 | 0.000 | | | | | serial_clk
2.186 | 2.186 | tCL | RR | 7 | PLL_R[1] | u_hdmi/u_clk/u_pll/CLKOUT0
3.113 | 0.927 | tNET | RR | 1 | R34C146[1][A] | u_hdmi/rstn_ser_2_s0/CLK
3.243 | 0.130 | tC2Q | RR | 4 | R34C146[1][A] | u_hdmi/rstn_ser_2_s0/Q
3.459 | 0.216 | tNET | RR | 1 | IOR39[A] | u_hdmi/u_serializer/lanes[2].u_oser/RESET

Data Required Path:

AT | DELAY | TYPE | RF | FANOUT | LOC | NODE
-4.000 | -4.000 | | | | | active clock edge time
-4.000 | 0.000 | | | | | serial_clk
-1.814 | 2.186 | tCL | FF | 7 | PLL_R[1] | u_hdmi/u_clk/u_pll/CLKOUT0
-1.814 | 0.000 | tNET | FF | 1 | IOR39[A] | u_hdmi/u_serializer/lanes[2].u_oser/FCLK
-1.678 | 0.136 | tHld | | 1 | IOR39[A] | u_hdmi/u_serializer/lanes[2].u_oser

Path Statistics:

Clock Skew | -0.927
Hold Relationship | -4.000
Logic Level | 1
Arrival Clock Path Delay | cell: 0.000, 0.000%; route: 0.927, 100.000%
Arrival Data Path Delay | cell: 0.000, 0.000%; route: 0.216, 62.500%; tC2Q: 0.130, 37.500%
Required Clock Path Delay | cell: 0.000, 0.000%; route: 0.000, 0.000%

### Path11

Path Summary:

Slack | 5.195
Data Arrival Time | 3.517
Data Required Time | -1.678
From | u_hdmi/rstn_ser_2_s0
To | u_hdmi/u_serializer/lanes[0].u_oser
Launch Clk | serial_clk:[R]
Latch Clk | serial_clk:[F]

Data Arrival Path:

AT | DELAY | TYPE | RF | FANOUT | LOC | NODE
0.000 | 0.000 | | | | | active clock edge time
0.000 | 0.000 | | | | | serial_clk
2.186 | 2.186 | tCL | RR | 7 | PLL_R[1] | u_hdmi/u_clk/u_pll/CLKOUT0
3.113 | 0.927 | tNET | RR | 1 | R34C146[1][A] | u_hdmi/rstn_ser_2_s0/CLK
3.243 | 0.130 | tC2Q | RR | 4 | R34C146[1][A] | u_hdmi/rstn_ser_2_s0/Q
3.517 | 0.274 | tNET | RR | 1 | IOR26[A] | u_hdmi/u_serializer/lanes[0].u_oser/RESET

Data Required Path:

AT | DELAY | TYPE | RF | FANOUT | LOC | NODE
-4.000 | -4.000 | | | | | active clock edge time
-4.000 | 0.000 | | | | | serial_clk
-1.814 | 2.186 | tCL | FF | 7 | PLL_R[1] | u_hdmi/u_clk/u_pll/CLKOUT0
-1.814 | 0.000 | tNET | FF | 1 | IOR26[A] | u_hdmi/u_serializer/lanes[0].u_oser/FCLK
-1.678 | 0.136 | tHld | | 1 | IOR26[A] | u_hdmi/u_serializer/lanes[0].u_oser

Path Statistics:

Clock Skew | -0.927
Hold Relationship | -4.000
Logic Level | 1
Arrival Clock Path Delay | cell: 0.000, 0.000%; route: 0.927, 100.000%
Arrival Data Path Delay | cell: 0.000, 0.000%; route: 0.274, 67.929%; tC2Q: 0.130, 32.071%
Required Clock Path Delay | cell: 0.000, 0.000%; route: 0.000, 0.000%

### Path12

Path Summary:

Slack | 5.283
Data Arrival Time | 3.605
Data Required Time | -1.678
From | u_hdmi/rstn_ser_2_s0
To | u_hdmi/u_serializer/lanes[3].u_oser
Launch Clk | serial_clk:[R]
Latch Clk | serial_clk:[F]

Data Arrival Path:

AT | DELAY | TYPE | RF | FANOUT | LOC | NODE
0.000 | 0.000 | | | | | active clock edge time
0.000 | 0.000 | | | | | serial_clk
2.186 | 2.186 | tCL | RR | 7 | PLL_R[1] | u_hdmi/u_clk/u_pll/CLKOUT0
3.113 | 0.927 | tNET | RR | 1 | R34C146[1][A] | u_hdmi/rstn_ser_2_s0/CLK
3.243 | 0.130 | tC2Q | RR | 4 | R34C146[1][A] | u_hdmi/rstn_ser_2_s0/Q
3.605 | 0.363 | tNET | RR | 1 | IOR24[A] | u_hdmi/u_serializer/lanes[3].u_oser/RESET

Data Required Path:

AT | DELAY | TYPE | RF | FANOUT | LOC | NODE
-4.000 | -4.000 | | | | | active clock edge time
-4.000 | 0.000 | | | | | serial_clk
-1.814 | 2.186 | tCL | FF | 7 | PLL_R[1] | u_hdmi/u_clk/u_pll/CLKOUT0
-1.814 | 0.000 | tNET | FF | 1 | IOR24[A] | u_hdmi/u_serializer/lanes[3].u_oser/FCLK
-1.678 | 0.136 | tHld | | 1 | IOR24[A] | u_hdmi/u_serializer/lanes[3].u_oser

Path Statistics:

Clock Skew | -0.927
Hold Relationship | -4.000
Logic Level | 1
Arrival Clock Path Delay | cell: 0.000, 0.000%; route: 0.927, 100.000%
Arrival Data Path Delay | cell: 0.000, 0.000%; route: 0.363, 73.675%; tC2Q: 0.130, 26.325%
Required Clock Path Delay | cell: 0.000, 0.000%; route: 0.000, 0.000%

## Minimum Pulse Width Report:

#### Report Command:report_min_pulse_width -nworst 10 -detail

### MPW1

MPW Summary:

Slack: | 0.087
Actual Width: | 0.312
Required Width: | 0.225
Type: | Low Pulse Width
Clock: | serial_clk
Objects: | u_hdmi/rstn_ser_2_s0

Late clock Path:

AT | DELAY | TYPE | RF | NODE
4.000 | 0.000 | | | active clock edge time
4.000 | 0.000 | | | serial_clk
8.133 | 4.133 | tCL | FF | u_hdmi/u_clk/u_pll/CLKOUT0
10.801 | 2.667 | tNET | FF | u_hdmi/rstn_ser_2_s0/CLK

Early clock Path:

AT | DELAY | TYPE | RF | NODE
8.000 | 0.000 | | | active clock edge time
8.000 | 0.000 | | | serial_clk
10.186 | 2.186 | tCL | RR | u_hdmi/u_clk/u_pll/CLKOUT0
11.113 | 0.927 | tNET | RR | u_hdmi/rstn_ser_2_s0/CLK

### MPW2

MPW Summary:

Slack: | 0.087
Actual Width: | 0.312
Required Width: | 0.225
Type: | Low Pulse Width
Clock: | serial_clk
Objects: | u_hdmi/rstn_ser_1_s0

Late clock Path:

AT | DELAY | TYPE | RF | NODE
4.000 | 0.000 | | | active clock edge time
4.000 | 0.000 | | | serial_clk
8.133 | 4.133 | tCL | FF | u_hdmi/u_clk/u_pll/CLKOUT0
10.801 | 2.667 | tNET | FF | u_hdmi/rstn_ser_1_s0/CLK

Early clock Path:

AT | DELAY | TYPE | RF | NODE
8.000 | 0.000 | | | active clock edge time
8.000 | 0.000 | | | serial_clk
10.186 | 2.186 | tCL | RR | u_hdmi/u_clk/u_pll/CLKOUT0
11.113 | 0.927 | tNET | RR | u_hdmi/rstn_ser_1_s0/CLK

### MPW3

MPW Summary:

Slack: | 0.087
Actual Width: | 0.312
Required Width: | 0.225
Type: | Low Pulse Width
Clock: | serial_clk
Objects: | u_hdmi/rstn_ser_0_s0

Late clock Path:

AT | DELAY | TYPE | RF | NODE
4.000 | 0.000 | | | active clock edge time
4.000 | 0.000 | | | serial_clk
8.133 | 4.133 | tCL | FF | u_hdmi/u_clk/u_pll/CLKOUT0
10.801 | 2.667 | tNET | FF | u_hdmi/rstn_ser_0_s0/CLK

Early clock Path:

AT | DELAY | TYPE | RF | NODE
8.000 | 0.000 | | | active clock edge time
8.000 | 0.000 | | | serial_clk
10.186 | 2.186 | tCL | RR | u_hdmi/u_clk/u_pll/CLKOUT0
11.113 | 0.927 | tNET | RR | u_hdmi/rstn_ser_0_s0/CLK

### MPW4

MPW Summary:

Slack: | 0.088
Actual Width: | 0.313
Required Width: | 0.225
Type: | High Pulse Width
Clock: | serial_clk
Objects: | u_hdmi/rstn_ser_2_s0

Late clock Path:

AT | DELAY | TYPE | RF | NODE
0.000 | 0.000 | | | active clock edge time
0.000 | 0.000 | | | serial_clk
4.133 | 4.133 | tCL | RR | u_hdmi/u_clk/u_pll/CLKOUT0
6.804 | 2.671 | tNET | RR | u_hdmi/rstn_ser_2_s0/CLK

Early clock Path:

AT | DELAY | TYPE | RF | NODE
4.000 | 0.000 | | | active clock edge time
4.000 | 0.000 | | | serial_clk
6.186 | 2.186 | tCL | FF | u_hdmi/u_clk/u_pll/CLKOUT0
7.118 | 0.931 | tNET | FF | u_hdmi/rstn_ser_2_s0/CLK

### MPW5

MPW Summary:

Slack: | 0.088
Actual Width: | 0.313
Required Width: | 0.225
Type: | High Pulse Width
Clock: | serial_clk
Objects: | u_hdmi/rstn_ser_1_s0

Late clock Path:

AT | DELAY | TYPE | RF | NODE
0.000 | 0.000 | | | active clock edge time
0.000 | 0.000 | | | serial_clk
4.133 | 4.133 | tCL | RR | u_hdmi/u_clk/u_pll/CLKOUT0
6.804 | 2.671 | tNET | RR | u_hdmi/rstn_ser_1_s0/CLK

Early clock Path:

AT | DELAY | TYPE | RF | NODE
4.000 | 0.000 | | | active clock edge time
4.000 | 0.000 | | | serial_clk
6.186 | 2.186 | tCL | FF | u_hdmi/u_clk/u_pll/CLKOUT0
7.118 | 0.931 | tNET | FF | u_hdmi/rstn_ser_1_s0/CLK

### MPW6

MPW Summary:

Slack: | 0.088
Actual Width: | 0.313
Required Width: | 0.225
Type: | High Pulse Width
Clock: | serial_clk
Objects: | u_hdmi/rstn_ser_0_s0

Late clock Path:

AT | DELAY | TYPE | RF | NODE
0.000 | 0.000 | | | active clock edge time
0.000 | 0.000 | | | serial_clk
4.133 | 4.133 | tCL | RR | u_hdmi/u_clk/u_pll/CLKOUT0
6.804 | 2.671 | tNET | RR | u_hdmi/rstn_ser_0_s0/CLK

Early clock Path:

AT | DELAY | TYPE | RF | NODE
4.000 | 0.000 | | | active clock edge time
4.000 | 0.000 | | | serial_clk
6.186 | 2.186 | tCL | FF | u_hdmi/u_clk/u_pll/CLKOUT0
7.118 | 0.931 | tNET | FF | u_hdmi/rstn_ser_0_s0/CLK

### MPW7

MPW Summary:

Slack: | 6.809
Actual Width: | 7.709
Required Width: | 0.900
Type: | Low Pulse Width
Clock: | clk_sys
Objects: | g_sound.u_looper/mem_mem_0_7_s

Late clock Path:

AT | DELAY | TYPE | RF | NODE
10.000 | 0.000 | | | active clock edge time
10.000 | 0.000 | | | clk_sys
10.000 | 0.000 | tCL | FF | clk_ibuf/I
11.376 | 1.376 | tINS | FF | clk_ibuf/O
14.661 | 3.285 | tNET | FF | g_sound.u_looper/mem_mem_0_7_s/CLKB

Early clock Path:

AT | DELAY | TYPE | RF | NODE
20.000 | 0.000 | | | active clock edge time
20.000 | 0.000 | | | clk_sys
20.000 | 0.000 | tCL | RR | clk_ibuf/I
20.952 | 0.952 | tINS | RR | clk_ibuf/O
22.371 | 1.418 | tNET | RR | g_sound.u_looper/mem_mem_0_7_s/CLKB

### MPW8

MPW Summary:

Slack: | 6.809
Actual Width: | 7.709
Required Width: | 0.900
Type: | Low Pulse Width
Clock: | clk_sys
Objects: | g_sound.u_looper/ep_mem_ep_mem_0_0_s

Late clock Path:

AT | DELAY | TYPE | RF | NODE
10.000 | 0.000 | | | active clock edge time
10.000 | 0.000 | | | clk_sys
10.000 | 0.000 | tCL | FF | clk_ibuf/I
11.376 | 1.376 | tINS | FF | clk_ibuf/O
14.661 | 3.285 | tNET | FF | g_sound.u_looper/ep_mem_ep_mem_0_0_s/CLKA

Early clock Path:

AT | DELAY | TYPE | RF | NODE
20.000 | 0.000 | | | active clock edge time
20.000 | 0.000 | | | clk_sys
20.000 | 0.000 | tCL | RR | clk_ibuf/I
20.952 | 0.952 | tINS | RR | clk_ibuf/O
22.371 | 1.418 | tNET | RR | g_sound.u_looper/ep_mem_ep_mem_0_0_s/CLKA

### MPW9

MPW Summary:

Slack: | 6.809
Actual Width: | 7.709
Required Width: | 0.900
Type: | Low Pulse Width
Clock: | clk_sys
Objects: | g_sound.u_looper/ep_mem_ep_mem_0_1_s

Late clock Path:

AT | DELAY | TYPE | RF | NODE
10.000 | 0.000 | | | active clock edge time
10.000 | 0.000 | | | clk_sys
10.000 | 0.000 | tCL | FF | clk_ibuf/I
11.376 | 1.376 | tINS | FF | clk_ibuf/O
14.661 | 3.285 | tNET | FF | g_sound.u_looper/ep_mem_ep_mem_0_1_s/CLKB

Early clock Path:

AT | DELAY | TYPE | RF | NODE
20.000 | 0.000 | | | active clock edge time
20.000 | 0.000 | | | clk_sys
20.000 | 0.000 | tCL | RR | clk_ibuf/I
20.952 | 0.952 | tINS | RR | clk_ibuf/O
22.371 | 1.418 | tNET | RR | g_sound.u_looper/ep_mem_ep_mem_0_1_s/CLKB

### MPW10

MPW Summary:

Slack: | 6.809
Actual Width: | 7.709
Required Width: | 0.900
Type: | Low Pulse Width
Clock: | clk_sys
Objects: | g_sound.u_looper/ep_mem_ep_mem_0_4_s

Late clock Path:

AT | DELAY | TYPE | RF | NODE
10.000 | 0.000 | | | active clock edge time
10.000 | 0.000 | | | clk_sys
10.000 | 0.000 | tCL | FF | clk_ibuf/I
11.376 | 1.376 | tINS | FF | clk_ibuf/O
14.661 | 3.285 | tNET | FF | g_sound.u_looper/ep_mem_ep_mem_0_4_s/CLKA

Early clock Path:

AT | DELAY | TYPE | RF | NODE
20.000 | 0.000 | | | active clock edge time
20.000 | 0.000 | | | clk_sys
20.000 | 0.000 | tCL | RR | clk_ibuf/I
20.952 | 0.952 | tINS | RR | clk_ibuf/O
22.371 | 1.418 | tNET | RR | g_sound.u_looper/ep_mem_ep_mem_0_4_s/CLKA

## High Fanout Nets Report:

#### Report Command:report_high_fanout_nets -max_nets 10

FANOUT | NET NAME | WORST SLACK | MAX DELAY
17287 | clk_d | 0.306 | 3.307
11918 | rst_n_sync | 6.012 | 2.585
1414 | tick_audio | 10.208 | 3.005
805 | g_sound.u_looper/ramp_sc[3] | 3.687 | 4.504
564 | g_t3.rot_cnt[0] | 6.033 | 5.287
492 | g_sound.af_sample_ch[2] | 0.713 | 5.304
407 | g_sound.u_looper/ramp_sc[2] | 6.349 | 3.846
391 | g_sound.am_axis_out[3] | 7.944 | 3.945
376 | g_sound.u_looper/ramp_inc_3525 | 7.086 | 2.553
373 | g_sound.u_looper/close_scan_r[3] | 8.322 | 2.635

## Route Congestions Report:

#### Report Command:report_route_congestion -max_grids 10

GRID LOC | ROUTE CONGESTIONS
R30C76 | 91.67%
R30C77 | 88.89%
R30C79 | 88.89%
R30C82 | 88.89%
R30C86 | 87.50%
R30C78 | 86.11%
R30C83 | 86.11%
R30C95 | 86.11%
R30C97 | 86.11%
R30C93 | 84.72%

## Timing Exceptions Report:

### Setup Analysis Report

#### Report Command:report_exceptions -setup -max_paths 5 -max_common_paths 1

#### Timing Path Constraint[1]: set_max_delay -from [get_clocks {clk_sys}] -to [get_clocks {clk_sys}] 17.8

### Path1

Path Summary:

Slack | 0.306
Data Arrival Time | 21.570
Data Required Time | 21.876
From | g_sound.u_fader_gear/gear_o_0_s0
To | g_sound.u_vibrato_lfo/rate_inc_q_25_s0
Launch Clk | clk_sys:[R]
Latch Clk | clk_sys:[R]

Data Arrival Path:

AT | DELAY | TYPE | RF | FANOUT | LOC | NODE
0.000 | 0.000 | | | | | active clock edge time
0.000 | 0.000 | | | | | clk_sys
0.000 | 0.000 | tCL | RR | 1 | IOB117[B] | clk_ibuf/I
1.288 | 1.288 | tINS | RR | 17287 | IOB117[B] | clk_ibuf/O
4.142 | 2.854 | tNET | RR | 1 | R60C109[0][A] | g_sound.u_fader_gear/gear_o_0_s0/CLK
4.486 | 0.344 | tC2Q | RR | 23 | R60C109[0][A] | g_sound.u_fader_gear/gear_o_0_s0/Q
6.011 | 1.524 | tNET | RR | 1 | R66C119[3][B] | g_sound.u_fader_gear/g_sound.vib_rate_sel_0_s/I0
6.458 | 0.448 | tINS | RR | 1 | R66C119[3][B] | g_sound.u_fader_gear/g_sound.vib_rate_sel_0_s/F
7.519 | 1.061 | tNET | RR | 97 | DSP_R65[31] | g_sound.u_vibrato_lfo/rate_product_0_s/A[0]
10.176 | 2.657 | tINS | RR | 3 | DSP_R65[31] | g_sound.u_vibrato_lfo/rate_product_0_s/DOUT[15]
11.142 | 0.966 | tNET | RR | 1 | R68C116[0][A] | g_sound.u_vibrato_lfo/rate_target_w_5_s3/I2
11.607 | 0.465 | tINS | RR | 3 | R68C116[0][A] | g_sound.u_vibrato_lfo/rate_target_w_5_s3/F
11.753 | 0.146 | tNET | RR | 1 | R69C116[2][B] | g_sound.u_vibrato_lfo/rate_target_w_8_s3/I0
12.218 | 0.465 | tINS | RR | 4 | R69C116[2][B] | g_sound.u_vibrato_lfo/rate_target_w_8_s3/F
12.537 | 0.319 | tNET | RR | 1 | R68C117[2][A] | g_sound.u_vibrato_lfo/rate_target_w_9_s2/I1
13.002 | 0.465 | tINS | RR | 8 | R68C117[2][A] | g_sound.u_vibrato_lfo/rate_target_w_9_s2/F
13.614 | 0.612 | tNET | RR | 2 | R71C116[1][B] | g_sound.u_vibrato_lfo/n462_s/I0
14.114 | 0.501 | tINS | RF | 1 | R71C116[1][B] | g_sound.u_vibrato_lfo/n462_s/COUT
14.114 | 0.000 | tNET | FF | 2 | R71C116[2][A] | g_sound.u_vibrato_lfo/n461_s/CIN
14.159 | 0.045 | tINS | FR | 1 | R71C116[2][A] | g_sound.u_vibrato_lfo/n461_s/COUT
14.159 | 0.000 | tNET | RR | 2 | R71C116[2][B] | g_sound.u_vibrato_lfo/n460_s/CIN
14.204 | 0.045 | tINS | RR | 1 | R71C116[2][B] | g_sound.u_vibrato_lfo/n460_s/COUT
14.204 | 0.000 | tNET | RR | 2 | R71C117[0][A] | g_sound.u_vibrato_lfo/n459_s/CIN
14.249 | 0.045 | tINS | RR | 1 | R71C117[0][A] | g_sound.u_vibrato_lfo/n459_s/COUT
14.249 | 0.000 | tNET | RR | 2 | R71C117[0][B] | g_sound.u_vibrato_lfo/n458_s/CIN
14.294 | 0.045 | tINS | RR | 1 | R71C117[0][B] | g_sound.u_vibrato_lfo/n458_s/COUT
14.294 | 0.000 | tNET | RR | 2 | R71C117[1][A] | g_sound.u_vibrato_lfo/n457_s/CIN
14.339 | 0.045 | tINS | RR | 1 | R71C117[1][A] | g_sound.u_vibrato_lfo/n457_s/COUT
14.339 | 0.000 | tNET | RR | 2 | R71C117[1][B] | g_sound.u_vibrato_lfo/n456_s/CIN
14.384 | 0.045 | tINS | RR | 1 | R71C117[1][B] | g_sound.u_vibrato_lfo/n456_s/COUT
14.384 | 0.000 | tNET | RR | 2 | R71C117[2][A] | g_sound.u_vibrato_lfo/n455_s/CIN
14.429 | 0.045 | tINS | RR | 1 | R71C117[2][A] | g_sound.u_vibrato_lfo/n455_s/COUT
14.429 | 0.000 | tNET | RR | 2 | R71C117[2][B] | g_sound.u_vibrato_lfo/n454_s/CIN
14.474 | 0.045 | tINS | RR | 1 | R71C117[2][B] | g_sound.u_vibrato_lfo/n454_s/COUT
14.474 | 0.000 | tNET | RR | 2 | R71C118[0][A] | g_sound.u_vibrato_lfo/n453_s/CIN
14.519 | 0.045 | tINS | RR | 1 | R71C118[0][A] | g_sound.u_vibrato_lfo/n453_s/COUT
14.519 | 0.000 | tNET | RR | 2 | R71C118[0][B] | g_sound.u_vibrato_lfo/n452_s/CIN
14.564 | 0.045 | tINS | RR | 1 | R71C118[0][B] | g_sound.u_vibrato_lfo/n452_s/COUT
14.564 | 0.000 | tNET | RR | 2 | R71C118[1][A] | g_sound.u_vibrato_lfo/n451_s/CIN
14.609 | 0.045 | tINS | RR | 1 | R71C118[1][A] | g_sound.u_vibrato_lfo/n451_s/COUT
14.609 | 0.000 | tNET | RR | 2 | R71C118[1][B] | g_sound.u_vibrato_lfo/n450_s/CIN
14.654 | 0.045 | tINS | RR | 1 | R71C118[1][B] | g_sound.u_vibrato_lfo/n450_s/COUT
14.654 | 0.000 | tNET | RR | 2 | R71C118[2][A] | g_sound.u_vibrato_lfo/n449_s/CIN
14.699 | 0.045 | tINS | RR | 1 | R71C118[2][A] | g_sound.u_vibrato_lfo/n449_s/COUT
14.699 | 0.000 | tNET | RR | 2 | R71C118[2][B] | g_sound.u_vibrato_lfo/n448_s/CIN
14.970 | 0.271 | tINS | RF | 1 | R71C118[2][B] | g_sound.u_vibrato_lfo/n448_s/SUM
14.975 | 0.005 | tNET | FF | 1 | R71C118[3][A] | g_sound.u_vibrato_lfo/n651_s19/I1
15.423 | 0.448 | tINS | FR | 1 | R71C118[3][A] | g_sound.u_vibrato_lfo/n651_s19/F
15.425 | 0.002 | tNET | RR | 1 | R71C118[3][B] | g_sound.u_vibrato_lfo/n651_s18/I3
15.798 | 0.373 | tINS | RR | 1 | R71C118[3][B] | g_sound.u_vibrato_lfo/n651_s18/F
16.111 | 0.313 | tNET | RR | 1 | R72C116[0][B] | g_sound.u_vibrato_lfo/n651_s15/I3
16.526 | 0.415 | tINS | RR | 1 | R72C116[0][B] | g_sound.u_vibrato_lfo/n651_s15/F
16.821 | 0.295 | tNET | RR | 1 | R71C116[3][A] | g_sound.u_vibrato_lfo/n651_s11/I3
17.290 | 0.469 | tINS | RR | 1 | R71C116[3][A] | g_sound.u_vibrato_lfo/n651_s11/F
17.657 | 0.367 | tNET | RR | 1 | R71C119[3][B] | g_sound.u_vibrato_lfo/n651_s7/I3
18.105 | 0.448 | tINS | RR | 4 | R71C119[3][B] | g_sound.u_vibrato_lfo/n651_s7/F
18.820 | 0.715 | tNET | RR | 1 | R72C115[1][B] | g_sound.u_vibrato_lfo/n651_s2/I0
19.294 | 0.474 | tINS | RR | 19 | R72C115[1][B] | g_sound.u_vibrato_lfo/n651_s2/F
21.105 | 1.811 | tNET | RR | 1 | R71C122[1][A] | g_sound.u_vibrato_lfo/n668_s0/I0
21.570 | 0.465 | tINS | RR | 1 | R71C122[1][A] | g_sound.u_vibrato_lfo/n668_s0/F
21.570 | 0.000 | tNET | RR | 1 | R71C122[1][A] | g_sound.u_vibrato_lfo/rate_inc_q_25_s0/D

Data Required Path:

AT | DELAY | TYPE | RF | FANOUT | LOC | NODE
17.800 | 17.800 | | | | | active clock edge time
17.800 | 0.000 | | | | | clk_sys
17.800 | 0.000 | tCL | RR | 1 | IOB117[B] | clk_ibuf/I
19.088 | 1.288 | tINS | RR | 17287 | IOB117[B] | clk_ibuf/O
21.933 | 2.845 | tNET | RR | 1 | R71C122[1][A] | g_sound.u_vibrato_lfo/rate_inc_q_25_s0/CLK
21.876 | -0.057 | tSu | | 1 | R71C122[1][A] | g_sound.u_vibrato_lfo/rate_inc_q_25_s0

Path Statistics:

Clock Skew | -0.008
Setup Relationship | 17.800
Logic Level | 16
Arrival Clock Path Delay | cell: 1.288, 31.105%; route: 2.854, 68.895%
Arrival Data Path Delay | cell: 8.946, 51.334%; route: 8.137, 46.691%; tC2Q: 0.344, 1.975%
Required Clock Path Delay | cell: 1.288, 31.169%; route: 2.845, 68.831%

### Path2

Path Summary:

Slack | 0.315
Data Arrival Time | 21.570
Data Required Time | 21.885
From | g_sound.u_fader_gear/gear_o_0_s0
To | g_sound.u_vibrato_lfo/rate_inc_q_10_s0
Launch Clk | clk_sys:[R]
Latch Clk | clk_sys:[R]

Data Arrival Path:

AT | DELAY | TYPE | RF | FANOUT | LOC | NODE
0.000 | 0.000 | | | | | active clock edge time
0.000 | 0.000 | | | | | clk_sys
0.000 | 0.000 | tCL | RR | 1 | IOB117[B] | clk_ibuf/I
1.288 | 1.288 | tINS | RR | 17287 | IOB117[B] | clk_ibuf/O
4.142 | 2.854 | tNET | RR | 1 | R60C109[0][A] | g_sound.u_fader_gear/gear_o_0_s0/CLK
4.486 | 0.344 | tC2Q | RR | 23 | R60C109[0][A] | g_sound.u_fader_gear/gear_o_0_s0/Q
6.011 | 1.524 | tNET | RR | 1 | R66C119[3][B] | g_sound.u_fader_gear/g_sound.vib_rate_sel_0_s/I0
6.458 | 0.448 | tINS | RR | 1 | R66C119[3][B] | g_sound.u_fader_gear/g_sound.vib_rate_sel_0_s/F
7.519 | 1.061 | tNET | RR | 97 | DSP_R65[31] | g_sound.u_vibrato_lfo/rate_product_0_s/A[0]
10.176 | 2.657 | tINS | RR | 3 | DSP_R65[31] | g_sound.u_vibrato_lfo/rate_product_0_s/DOUT[15]
11.142 | 0.966 | tNET | RR | 1 | R68C116[0][A] | g_sound.u_vibrato_lfo/rate_target_w_5_s3/I2
11.607 | 0.465 | tINS | RR | 3 | R68C116[0][A] | g_sound.u_vibrato_lfo/rate_target_w_5_s3/F
11.753 | 0.146 | tNET | RR | 1 | R69C116[2][B] | g_sound.u_vibrato_lfo/rate_target_w_8_s3/I0
12.218 | 0.465 | tINS | RR | 4 | R69C116[2][B] | g_sound.u_vibrato_lfo/rate_target_w_8_s3/F
12.537 | 0.319 | tNET | RR | 1 | R68C117[2][A] | g_sound.u_vibrato_lfo/rate_target_w_9_s2/I1
13.002 | 0.465 | tINS | RR | 8 | R68C117[2][A] | g_sound.u_vibrato_lfo/rate_target_w_9_s2/F
13.614 | 0.612 | tNET | RR | 2 | R71C116[1][B] | g_sound.u_vibrato_lfo/n462_s/I0
14.114 | 0.501 | tINS | RF | 1 | R71C116[1][B] | g_sound.u_vibrato_lfo/n462_s/COUT
14.114 | 0.000 | tNET | FF | 2 | R71C116[2][A] | g_sound.u_vibrato_lfo/n461_s/CIN
14.159 | 0.045 | tINS | FR | 1 | R71C116[2][A] | g_sound.u_vibrato_lfo/n461_s/COUT
14.159 | 0.000 | tNET | RR | 2 | R71C116[2][B] | g_sound.u_vibrato_lfo/n460_s/CIN
14.204 | 0.045 | tINS | RR | 1 | R71C116[2][B] | g_sound.u_vibrato_lfo/n460_s/COUT
14.204 | 0.000 | tNET | RR | 2 | R71C117[0][A] | g_sound.u_vibrato_lfo/n459_s/CIN
14.249 | 0.045 | tINS | RR | 1 | R71C117[0][A] | g_sound.u_vibrato_lfo/n459_s/COUT
14.249 | 0.000 | tNET | RR | 2 | R71C117[0][B] | g_sound.u_vibrato_lfo/n458_s/CIN
14.294 | 0.045 | tINS | RR | 1 | R71C117[0][B] | g_sound.u_vibrato_lfo/n458_s/COUT
14.294 | 0.000 | tNET | RR | 2 | R71C117[1][A] | g_sound.u_vibrato_lfo/n457_s/CIN
14.339 | 0.045 | tINS | RR | 1 | R71C117[1][A] | g_sound.u_vibrato_lfo/n457_s/COUT
14.339 | 0.000 | tNET | RR | 2 | R71C117[1][B] | g_sound.u_vibrato_lfo/n456_s/CIN
14.384 | 0.045 | tINS | RR | 1 | R71C117[1][B] | g_sound.u_vibrato_lfo/n456_s/COUT
14.384 | 0.000 | tNET | RR | 2 | R71C117[2][A] | g_sound.u_vibrato_lfo/n455_s/CIN
14.429 | 0.045 | tINS | RR | 1 | R71C117[2][A] | g_sound.u_vibrato_lfo/n455_s/COUT
14.429 | 0.000 | tNET | RR | 2 | R71C117[2][B] | g_sound.u_vibrato_lfo/n454_s/CIN
14.474 | 0.045 | tINS | RR | 1 | R71C117[2][B] | g_sound.u_vibrato_lfo/n454_s/COUT
14.474 | 0.000 | tNET | RR | 2 | R71C118[0][A] | g_sound.u_vibrato_lfo/n453_s/CIN
14.519 | 0.045 | tINS | RR | 1 | R71C118[0][A] | g_sound.u_vibrato_lfo/n453_s/COUT
14.519 | 0.000 | tNET | RR | 2 | R71C118[0][B] | g_sound.u_vibrato_lfo/n452_s/CIN
14.564 | 0.045 | tINS | RR | 1 | R71C118[0][B] | g_sound.u_vibrato_lfo/n452_s/COUT
14.564 | 0.000 | tNET | RR | 2 | R71C118[1][A] | g_sound.u_vibrato_lfo/n451_s/CIN
14.609 | 0.045 | tINS | RR | 1 | R71C118[1][A] | g_sound.u_vibrato_lfo/n451_s/COUT
14.609 | 0.000 | tNET | RR | 2 | R71C118[1][B] | g_sound.u_vibrato_lfo/n450_s/CIN
14.654 | 0.045 | tINS | RR | 1 | R71C118[1][B] | g_sound.u_vibrato_lfo/n450_s/COUT
14.654 | 0.000 | tNET | RR | 2 | R71C118[2][A] | g_sound.u_vibrato_lfo/n449_s/CIN
14.699 | 0.045 | tINS | RR | 1 | R71C118[2][A] | g_sound.u_vibrato_lfo/n449_s/COUT
14.699 | 0.000 | tNET | RR | 2 | R71C118[2][B] | g_sound.u_vibrato_lfo/n448_s/CIN
14.970 | 0.271 | tINS | RF | 1 | R71C118[2][B] | g_sound.u_vibrato_lfo/n448_s/SUM
14.975 | 0.005 | tNET | FF | 1 | R71C118[3][A] | g_sound.u_vibrato_lfo/n651_s19/I1
15.423 | 0.448 | tINS | FR | 1 | R71C118[3][A] | g_sound.u_vibrato_lfo/n651_s19/F
15.425 | 0.002 | tNET | RR | 1 | R71C118[3][B] | g_sound.u_vibrato_lfo/n651_s18/I3
15.798 | 0.373 | tINS | RR | 1 | R71C118[3][B] | g_sound.u_vibrato_lfo/n651_s18/F
16.111 | 0.313 | tNET | RR | 1 | R72C116[0][B] | g_sound.u_vibrato_lfo/n651_s15/I3
16.526 | 0.415 | tINS | RR | 1 | R72C116[0][B] | g_sound.u_vibrato_lfo/n651_s15/F
16.821 | 0.295 | tNET | RR | 1 | R71C116[3][A] | g_sound.u_vibrato_lfo/n651_s11/I3
17.290 | 0.469 | tINS | RR | 1 | R71C116[3][A] | g_sound.u_vibrato_lfo/n651_s11/F
17.657 | 0.367 | tNET | RR | 1 | R71C119[3][B] | g_sound.u_vibrato_lfo/n651_s7/I3
18.105 | 0.448 | tINS | RR | 4 | R71C119[3][B] | g_sound.u_vibrato_lfo/n651_s7/F
18.820 | 0.715 | tNET | RR | 1 | R72C115[1][B] | g_sound.u_vibrato_lfo/n651_s2/I0
19.294 | 0.474 | tINS | RR | 19 | R72C115[1][B] | g_sound.u_vibrato_lfo/n651_s2/F
21.105 | 1.811 | tNET | RR | 1 | R71C121[0][A] | g_sound.u_vibrato_lfo/n651_s0/I3
21.570 | 0.465 | tINS | RR | 1 | R71C121[0][A] | g_sound.u_vibrato_lfo/n651_s0/F
21.570 | 0.000 | tNET | RR | 1 | R71C121[0][A] | g_sound.u_vibrato_lfo/rate_inc_q_10_s0/D

Data Required Path:

AT | DELAY | TYPE | RF | FANOUT | LOC | NODE
17.800 | 17.800 | | | | | active clock edge time
17.800 | 0.000 | | | | | clk_sys
17.800 | 0.000 | tCL | RR | 1 | IOB117[B] | clk_ibuf/I
19.088 | 1.288 | tINS | RR | 17287 | IOB117[B] | clk_ibuf/O
21.942 | 2.854 | tNET | RR | 1 | R71C121[0][A] | g_sound.u_vibrato_lfo/rate_inc_q_10_s0/CLK
21.885 | -0.057 | tSu | | 1 | R71C121[0][A] | g_sound.u_vibrato_lfo/rate_inc_q_10_s0

Path Statistics:

Clock Skew | 0.000
Setup Relationship | 17.800
Logic Level | 16
Arrival Clock Path Delay | cell: 1.288, 31.105%; route: 2.854, 68.895%
Arrival Data Path Delay | cell: 8.946, 51.334%; route: 8.137, 46.691%; tC2Q: 0.344, 1.975%
Required Clock Path Delay | cell: 1.288, 31.105%; route: 2.854, 68.895%

### Path3

Path Summary:

Slack | 0.394
Data Arrival Time | 21.488
Data Required Time | 21.882
From | g_sound.u_fader_gear/gear_o_0_s0
To | g_sound.u_vibrato_lfo/rate_inc_q_13_s0
Launch Clk | clk_sys:[R]
Latch Clk | clk_sys:[R]

Data Arrival Path:

AT | DELAY | TYPE | RF | FANOUT | LOC | NODE
0.000 | 0.000 | | | | | active clock edge time
0.000 | 0.000 | | | | | clk_sys
0.000 | 0.000 | tCL | RR | 1 | IOB117[B] | clk_ibuf/I
1.288 | 1.288 | tINS | RR | 17287 | IOB117[B] | clk_ibuf/O
4.142 | 2.854 | tNET | RR | 1 | R60C109[0][A] | g_sound.u_fader_gear/gear_o_0_s0/CLK
4.486 | 0.344 | tC2Q | RR | 23 | R60C109[0][A] | g_sound.u_fader_gear/gear_o_0_s0/Q
6.011 | 1.524 | tNET | RR | 1 | R66C119[3][B] | g_sound.u_fader_gear/g_sound.vib_rate_sel_0_s/I0
6.458 | 0.448 | tINS | RR | 1 | R66C119[3][B] | g_sound.u_fader_gear/g_sound.vib_rate_sel_0_s/F
7.519 | 1.061 | tNET | RR | 97 | DSP_R65[31] | g_sound.u_vibrato_lfo/rate_product_0_s/A[0]
10.176 | 2.657 | tINS | RR | 3 | DSP_R65[31] | g_sound.u_vibrato_lfo/rate_product_0_s/DOUT[15]
11.142 | 0.966 | tNET | RR | 1 | R68C116[0][A] | g_sound.u_vibrato_lfo/rate_target_w_5_s3/I2
11.607 | 0.465 | tINS | RR | 3 | R68C116[0][A] | g_sound.u_vibrato_lfo/rate_target_w_5_s3/F
11.753 | 0.146 | tNET | RR | 1 | R69C116[2][B] | g_sound.u_vibrato_lfo/rate_target_w_8_s3/I0
12.218 | 0.465 | tINS | RR | 4 | R69C116[2][B] | g_sound.u_vibrato_lfo/rate_target_w_8_s3/F
12.537 | 0.319 | tNET | RR | 1 | R68C117[2][A] | g_sound.u_vibrato_lfo/rate_target_w_9_s2/I1
13.002 | 0.465 | tINS | RR | 8 | R68C117[2][A] | g_sound.u_vibrato_lfo/rate_target_w_9_s2/F
13.614 | 0.612 | tNET | RR | 2 | R71C116[1][B] | g_sound.u_vibrato_lfo/n462_s/I0
14.114 | 0.501 | tINS | RF | 1 | R71C116[1][B] | g_sound.u_vibrato_lfo/n462_s/COUT
14.114 | 0.000 | tNET | FF | 2 | R71C116[2][A] | g_sound.u_vibrato_lfo/n461_s/CIN
14.159 | 0.045 | tINS | FR | 1 | R71C116[2][A] | g_sound.u_vibrato_lfo/n461_s/COUT
14.159 | 0.000 | tNET | RR | 2 | R71C116[2][B] | g_sound.u_vibrato_lfo/n460_s/CIN
14.204 | 0.045 | tINS | RR | 1 | R71C116[2][B] | g_sound.u_vibrato_lfo/n460_s/COUT
14.204 | 0.000 | tNET | RR | 2 | R71C117[0][A] | g_sound.u_vibrato_lfo/n459_s/CIN
14.249 | 0.045 | tINS | RR | 1 | R71C117[0][A] | g_sound.u_vibrato_lfo/n459_s/COUT
14.249 | 0.000 | tNET | RR | 2 | R71C117[0][B] | g_sound.u_vibrato_lfo/n458_s/CIN
14.294 | 0.045 | tINS | RR | 1 | R71C117[0][B] | g_sound.u_vibrato_lfo/n458_s/COUT
14.294 | 0.000 | tNET | RR | 2 | R71C117[1][A] | g_sound.u_vibrato_lfo/n457_s/CIN
14.339 | 0.045 | tINS | RR | 1 | R71C117[1][A] | g_sound.u_vibrato_lfo/n457_s/COUT
14.339 | 0.000 | tNET | RR | 2 | R71C117[1][B] | g_sound.u_vibrato_lfo/n456_s/CIN
14.384 | 0.045 | tINS | RR | 1 | R71C117[1][B] | g_sound.u_vibrato_lfo/n456_s/COUT
14.384 | 0.000 | tNET | RR | 2 | R71C117[2][A] | g_sound.u_vibrato_lfo/n455_s/CIN
14.429 | 0.045 | tINS | RR | 1 | R71C117[2][A] | g_sound.u_vibrato_lfo/n455_s/COUT
14.429 | 0.000 | tNET | RR | 2 | R71C117[2][B] | g_sound.u_vibrato_lfo/n454_s/CIN
14.474 | 0.045 | tINS | RR | 1 | R71C117[2][B] | g_sound.u_vibrato_lfo/n454_s/COUT
14.474 | 0.000 | tNET | RR | 2 | R71C118[0][A] | g_sound.u_vibrato_lfo/n453_s/CIN
14.519 | 0.045 | tINS | RR | 1 | R71C118[0][A] | g_sound.u_vibrato_lfo/n453_s/COUT
14.519 | 0.000 | tNET | RR | 2 | R71C118[0][B] | g_sound.u_vibrato_lfo/n452_s/CIN
14.564 | 0.045 | tINS | RR | 1 | R71C118[0][B] | g_sound.u_vibrato_lfo/n452_s/COUT
14.564 | 0.000 | tNET | RR | 2 | R71C118[1][A] | g_sound.u_vibrato_lfo/n451_s/CIN
14.609 | 0.045 | tINS | RR | 1 | R71C118[1][A] | g_sound.u_vibrato_lfo/n451_s/COUT
14.609 | 0.000 | tNET | RR | 2 | R71C118[1][B] | g_sound.u_vibrato_lfo/n450_s/CIN
14.654 | 0.045 | tINS | RR | 1 | R71C118[1][B] | g_sound.u_vibrato_lfo/n450_s/COUT
14.654 | 0.000 | tNET | RR | 2 | R71C118[2][A] | g_sound.u_vibrato_lfo/n449_s/CIN
14.699 | 0.045 | tINS | RR | 1 | R71C118[2][A] | g_sound.u_vibrato_lfo/n449_s/COUT
14.699 | 0.000 | tNET | RR | 2 | R71C118[2][B] | g_sound.u_vibrato_lfo/n448_s/CIN
14.970 | 0.271 | tINS | RF | 1 | R71C118[2][B] | g_sound.u_vibrato_lfo/n448_s/SUM
14.975 | 0.005 | tNET | FF | 1 | R71C118[3][A] | g_sound.u_vibrato_lfo/n651_s19/I1
15.423 | 0.448 | tINS | FR | 1 | R71C118[3][A] | g_sound.u_vibrato_lfo/n651_s19/F
15.425 | 0.002 | tNET | RR | 1 | R71C118[3][B] | g_sound.u_vibrato_lfo/n651_s18/I3
15.798 | 0.373 | tINS | RR | 1 | R71C118[3][B] | g_sound.u_vibrato_lfo/n651_s18/F
16.111 | 0.313 | tNET | RR | 1 | R72C116[0][B] | g_sound.u_vibrato_lfo/n651_s15/I3
16.526 | 0.415 | tINS | RR | 1 | R72C116[0][B] | g_sound.u_vibrato_lfo/n651_s15/F
16.821 | 0.295 | tNET | RR | 1 | R71C116[3][A] | g_sound.u_vibrato_lfo/n651_s11/I3
17.290 | 0.469 | tINS | RR | 1 | R71C116[3][A] | g_sound.u_vibrato_lfo/n651_s11/F
17.657 | 0.367 | tNET | RR | 1 | R71C119[3][B] | g_sound.u_vibrato_lfo/n651_s7/I3
18.105 | 0.448 | tINS | RR | 4 | R71C119[3][B] | g_sound.u_vibrato_lfo/n651_s7/F
18.820 | 0.715 | tNET | RR | 1 | R72C115[1][B] | g_sound.u_vibrato_lfo/n651_s2/I0
19.294 | 0.474 | tINS | RR | 19 | R72C115[1][B] | g_sound.u_vibrato_lfo/n651_s2/F
21.227 | 1.933 | tNET | RR | 1 | R71C122[3][A] | g_sound.u_vibrato_lfo/n680_s0/I0
21.488 | 0.261 | tINS | RF | 1 | R71C122[3][A] | g_sound.u_vibrato_lfo/n680_s0/F
21.488 | 0.000 | tNET | FF | 1 | R71C122[3][A] | g_sound.u_vibrato_lfo/rate_inc_q_13_s0/D

Data Required Path:

AT | DELAY | TYPE | RF | FANOUT | LOC | NODE
17.800 | 17.800 | | | | | active clock edge time
17.800 | 0.000 | | | | | clk_sys
17.800 | 0.000 | tCL | RR | 1 | IOB117[B] | clk_ibuf/I
19.088 | 1.288 | tINS | RR | 17287 | IOB117[B] | clk_ibuf/O
21.933 | 2.845 | tNET | RR | 1 | R71C122[3][A] | g_sound.u_vibrato_lfo/rate_inc_q_13_s0/CLK
21.882 | -0.052 | tSu | | 1 | R71C122[3][A] | g_sound.u_vibrato_lfo/rate_inc_q_13_s0

Path Statistics:

Clock Skew | -0.008
Setup Relationship | 17.800
Logic Level | 16
Arrival Clock Path Delay | cell: 1.288, 31.105%; route: 2.854, 68.895%
Arrival Data Path Delay | cell: 8.743, 50.403%; route: 8.259, 47.612%; tC2Q: 0.344, 1.985%
Required Clock Path Delay | cell: 1.288, 31.169%; route: 2.845, 68.831%

### Path4

Path Summary:

Slack | 0.556
Data Arrival Time | 17.927
Data Required Time | 18.482
From | g_sound.u_calib_span/cur_axis_o_3_s1
To | g_sound.u_calib1/n909_s
Launch Clk | clk_sys:[R]
Latch Clk | clk_sys:[R]

Data Arrival Path:

AT | DELAY | TYPE | RF | FANOUT | LOC | NODE
0.000 | 0.000 | | | | | active clock edge time
0.000 | 0.000 | | | | | clk_sys
0.000 | 0.000 | tCL | RR | 1 | IOB117[B] | clk_ibuf/I
1.288 | 1.288 | tINS | RR | 17287 | IOB117[B] | clk_ibuf/O
4.142 | 2.854 | tNET | RR | 1 | R58C113[0][B] | g_sound.u_calib_span/cur_axis_o_3_s1/CLK
4.473 | 0.331 | tC2Q | RF | 74 | R58C113[0][B] | g_sound.u_calib_span/cur_axis_o_3_s1/Q
6.570 | 2.097 | tNET | FF | 1 | R58C104[0][A] | n4583_s1/I2
7.034 | 0.465 | tINS | FR | 13 | R58C104[0][A] | n4583_s1/F
10.921 | 3.887 | tNET | RR | 1 | R70C43[3][A] | g_sound.u_calib1/dclamp_7_s26/I2
11.182 | 0.261 | tINS | RF | 1 | R70C43[3][A] | g_sound.u_calib1/dclamp_7_s26/F
11.310 | 0.128 | tNET | FF | 1 | R69C43[3][A] | g_sound.u_calib1/dclamp_7_s18/I3
11.684 | 0.373 | tINS | FR | 1 | R69C43[3][A] | g_sound.u_calib1/dclamp_7_s18/F
11.826 | 0.142 | tNET | RR | 1 | R68C43[2][B] | g_sound.u_calib1/dclamp_7_s16/I3
12.299 | 0.474 | tINS | RR | 1 | R68C43[2][B] | g_sound.u_calib1/dclamp_7_s16/F
12.302 | 0.002 | tNET | RR | 1 | R68C43[3][B] | g_sound.u_calib1/dclamp_7_s21/I0
12.749 | 0.448 | tINS | RR | 1 | R68C43[3][B] | g_sound.u_calib1/dclamp_7_s21/F
12.891 | 0.142 | tNET | RR | 1 | R68C44[1][B] | g_sound.u_calib1/dclamp_7_s10/I1
13.306 | 0.415 | tINS | RR | 2 | R68C44[1][B] | g_sound.u_calib1/dclamp_7_s10/F
13.311 | 0.005 | tNET | RR | 1 | R68C44[1][A] | g_sound.u_calib1/dclamp_7_s6/I0
13.775 | 0.465 | tINS | RR | 2 | R68C44[1][A] | g_sound.u_calib1/dclamp_7_s6/F
14.212 | 0.436 | tNET | RR | 1 | R70C43[2][B] | g_sound.u_calib1/dclamp_7_s4/I1
14.676 | 0.465 | tINS | RR | 3 | R70C43[2][B] | g_sound.u_calib1/dclamp_7_s4/F
14.823 | 0.146 | tNET | RR | 1 | R70C42[2][B] | g_sound.u_calib1/dclamp_8_s9/I3
15.296 | 0.474 | tINS | RR | 1 | R70C42[2][B] | g_sound.u_calib1/dclamp_8_s9/F
15.438 | 0.142 | tNET | RR | 1 | R70C43[0][A] | g_sound.u_calib1/dclamp_8_s7/I1
15.853 | 0.415 | tINS | RR | 2 | R70C43[0][A] | g_sound.u_calib1/dclamp_8_s7/F
15.997 | 0.144 | tNET | RR | 1 | R70C44[2][B] | g_sound.u_calib1/dclamp_8_s4/I1
16.462 | 0.465 | tINS | RR | 9 | R70C44[2][B] | g_sound.u_calib1/dclamp_8_s4/F
16.910 | 0.448 | tNET | RR | 1 | R71C43[3][A] | g_sound.u_calib1/dclamp_0_s0/I3
17.357 | 0.448 | tINS | RR | 1 | R71C43[3][A] | g_sound.u_calib1/dclamp_0_s0/F
17.927 | 0.569 | tNET | RR | 1 | DSP_R65[13] | g_sound.u_calib1/n909_s/A[0]

Data Required Path:

AT | DELAY | TYPE | RF | FANOUT | LOC | NODE
17.800 | 17.800 | | | | | active clock edge time
17.800 | 0.000 | | | | | clk_sys
17.800 | 0.000 | tCL | RR | 1 | IOB117[B] | clk_ibuf/I
19.088 | 1.288 | tINS | RR | 17287 | IOB117[B] | clk_ibuf/O
21.942 | 2.854 | tNET | RR | 1 | DSP_R65[13] | g_sound.u_calib1/n909_s/CLK[0]
18.482 | -3.459 | tSu | | 1 | DSP_R65[13] | g_sound.u_calib1/n909_s

Path Statistics:

Clock Skew | 0.000
Setup Relationship | 17.800
Logic Level | 13
Arrival Clock Path Delay | cell: 1.288, 31.105%; route: 2.854, 68.895%
Arrival Data Path Delay | cell: 5.166, 37.477%; route: 8.288, 60.124%; tC2Q: 0.331, 2.399%
Required Clock Path Delay | cell: 1.288, 31.105%; route: 2.854, 68.895%

### Path5

Path Summary:

Slack | 0.574
Data Arrival Time | 17.908
Data Required Time | 18.482
From | g_sound.u_adc_farm/u_scan0/sample_channel_0_s0
To | g_sound.u_calib0/n909_s
Launch Clk | clk_sys:[R]
Latch Clk | clk_sys:[R]

Data Arrival Path:

AT | DELAY | TYPE | RF | FANOUT | LOC | NODE
0.000 | 0.000 | | | | | active clock edge time
0.000 | 0.000 | | | | | clk_sys
0.000 | 0.000 | tCL | RR | 1 | IOB117[B] | clk_ibuf/I
1.288 | 1.288 | tINS | RR | 17287 | IOB117[B] | clk_ibuf/O
4.150 | 2.862 | tNET | RR | 1 | R62C108[0][B] | g_sound.u_adc_farm/u_scan0/sample_channel_0_s0/CLK
4.495 | 0.344 | tC2Q | RR | 147 | R62C108[0][B] | g_sound.u_adc_farm/u_scan0/sample_channel_0_s0/Q
7.030 | 2.536 | tNET | RR | 1 | R64C56[0][A] | g_sound.u_calib0/n4_s16/I2
7.504 | 0.474 | tINS | RR | 1 | R64C56[0][A] | g_sound.u_calib0/n4_s16/F
7.504 | 0.000 | tNET | RR | 1 | R64C56[0][A] | g_sound.u_calib0/n4_s13/I0
7.627 | 0.123 | tINS | RR | 1 | R64C56[0][A] | g_sound.u_calib0/n4_s13/O
7.627 | 0.000 | tNET | RR | 1 | R64C56[0][B] | g_sound.u_calib0/n4_s11/I1
7.704 | 0.078 | tINS | RR | 51 | R64C56[0][B] | g_sound.u_calib0/n4_s11/O
9.299 | 1.595 | tNET | RR | 1 | R61C50[3][B] | g_sound.u_calib0/zero_rd_8_s2/I0
9.769 | 0.469 | tINS | RR | 5 | R61C50[3][B] | g_sound.u_calib0/zero_rd_8_s2/F
10.694 | 0.926 | tNET | RR | 1 | R58C56[0][B] | g_sound.u_calib0/dclamp_9_s11/I3
11.159 | 0.465 | tINS | RR | 1 | R58C56[0][B] | g_sound.u_calib0/dclamp_9_s11/F
11.283 | 0.124 | tNET | RR | 1 | R58C56[3][B] | g_sound.u_calib0/dclamp_9_s5/I1
11.731 | 0.448 | tINS | RR | 2 | R58C56[3][B] | g_sound.u_calib0/dclamp_9_s5/F
11.857 | 0.126 | tNET | RR | 1 | R58C56[3][A] | g_sound.u_calib0/dclamp_9_s3/I0
12.326 | 0.469 | tINS | RR | 18 | R58C56[3][A] | g_sound.u_calib0/dclamp_9_s3/F
14.162 | 1.836 | tNET | RR | 1 | R55C53[1][A] | g_sound.u_calib0/dclamp_8_s1/I1
14.626 | 0.465 | tINS | RR | 3 | R55C53[1][A] | g_sound.u_calib0/dclamp_8_s1/F
14.773 | 0.146 | tNET | RR | 1 | R55C54[0][B] | g_sound.u_calib0/dclamp_8_s11/I1
15.246 | 0.474 | tINS | RR | 1 | R55C54[0][B] | g_sound.u_calib0/dclamp_8_s11/F
15.370 | 0.124 | tNET | RR | 1 | R55C54[1][A] | g_sound.u_calib0/dclamp_8_s6/I3
15.606 | 0.236 | tINS | RR | 5 | R55C54[1][A] | g_sound.u_calib0/dclamp_8_s6/F
15.928 | 0.322 | tNET | RR | 1 | R52C54[1][A] | g_sound.u_calib0/dclamp_2_s2/I1
16.402 | 0.474 | tINS | RR | 3 | R52C54[1][A] | g_sound.u_calib0/dclamp_2_s2/F
16.548 | 0.146 | tNET | RR | 1 | R52C55[0][A] | g_sound.u_calib0/dclamp_0_s0/I3
16.963 | 0.415 | tINS | RR | 1 | R52C55[0][A] | g_sound.u_calib0/dclamp_0_s0/F
17.908 | 0.945 | tNET | RR | 1 | DSP_R47[14] | g_sound.u_calib0/n909_s/A[0]

Data Required Path:

AT | DELAY | TYPE | RF | FANOUT | LOC | NODE
17.800 | 17.800 | | | | | active clock edge time
17.800 | 0.000 | | | | | clk_sys
17.800 | 0.000 | tCL | RR | 1 | IOB117[B] | clk_ibuf/I
19.088 | 1.288 | tINS | RR | 17287 | IOB117[B] | clk_ibuf/O
21.942 | 2.854 | tNET | RR | 1 | DSP_R47[14] | g_sound.u_calib0/n909_s/CLK[0]
18.482 | -3.459 | tSu | | 1 | DSP_R47[14] | g_sound.u_calib0/n909_s

Path Statistics:

Clock Skew | -0.008
Setup Relationship | 17.800
Logic Level | 11
Arrival Clock Path Delay | cell: 1.288, 31.042%; route: 2.862, 68.958%
Arrival Data Path Delay | cell: 4.588, 33.347%; route: 8.826, 64.151%; tC2Q: 0.344, 2.502%
Required Clock Path Delay | cell: 1.288, 31.105%; route: 2.854, 68.895%

#### Timing Path Constraint[2]: set_max_delay -from [get_clocks {clk_sys}] -to [get_regs {u_hdmi/u_scope/gray_launch_*_s0 u_hdmi/u_scope/full_launch_s0 u_hdmi/u_scope/mode_launch_s0}] 10.000

### Path1

Path Summary:

Slack | 7.420
Data Arrival Time | 6.502
Data Required Time | 13.922
From | u_rst_sync/sync_chain_1_s0
To | u_hdmi/u_scope/full_launch_s0
Launch Clk | clk_sys:[R]
Latch Clk | clk_sys:[F]

Data Arrival Path:

AT | DELAY | TYPE | RF | FANOUT | LOC | NODE
0.000 | 0.000 | | | | | active clock edge time
0.000 | 0.000 | | | | | clk_sys
0.000 | 0.000 | tCL | RR | 1 | IOB117[B] | clk_ibuf/I
1.288 | 1.288 | tINS | RR | 17287 | IOB117[B] | clk_ibuf/O
4.150 | 2.862 | tNET | RR | 1 | R73C55[1][A] | u_rst_sync/sync_chain_1_s0/CLK
4.495 | 0.344 | tC2Q | RR | 11918 | R73C55[1][A] | u_rst_sync/sync_chain_1_s0/Q
6.502 | 2.007 | tNET | RR | 1 | R30C87[1][A] | u_hdmi/u_scope/full_launch_s0/RESET

Data Required Path:

AT | DELAY | TYPE | RF | FANOUT | LOC | NODE
10.000 | 10.000 | | | | | active clock edge time
10.000 | 0.000 | | | | | clk_sys
10.000 | 0.000 | tCL | FF | 1 | IOB117[B] | clk_ibuf/I
11.376 | 1.376 | tINS | FF | 17287 | IOB117[B] | clk_ibuf/O
14.207 | 2.831 | tNET | FF | 1 | R30C87[1][A] | u_hdmi/u_scope/full_launch_s0/CLK
13.922 | -0.286 | tSu | | 1 | R30C87[1][A] | u_hdmi/u_scope/full_launch_s0

Path Statistics:

Clock Skew | 0.057
Setup Relationship | 10.000
Logic Level | 1
Arrival Clock Path Delay | cell: 1.288, 31.042%; route: 2.862, 68.958%
Arrival Data Path Delay | cell: 0.000, 0.000%; route: 2.007, 85.359%; tC2Q: 0.344, 14.641%
Required Clock Path Delay | cell: 1.376, 32.714%; route: 2.831, 67.286%

### Path2

Path Summary:

Slack | 7.420
Data Arrival Time | 6.502
Data Required Time | 13.922
From | u_rst_sync/sync_chain_1_s0
To | u_hdmi/u_scope/gray_launch_0_s0
Launch Clk | clk_sys:[R]
Latch Clk | clk_sys:[F]

Data Arrival Path:

AT | DELAY | TYPE | RF | FANOUT | LOC | NODE
0.000 | 0.000 | | | | | active clock edge time
0.000 | 0.000 | | | | | clk_sys
0.000 | 0.000 | tCL | RR | 1 | IOB117[B] | clk_ibuf/I
1.288 | 1.288 | tINS | RR | 17287 | IOB117[B] | clk_ibuf/O
4.150 | 2.862 | tNET | RR | 1 | R73C55[1][A] | u_rst_sync/sync_chain_1_s0/CLK
4.495 | 0.344 | tC2Q | RR | 11918 | R73C55[1][A] | u_rst_sync/sync_chain_1_s0/Q
6.502 | 2.007 | tNET | RR | 1 | R30C87[1][B] | u_hdmi/u_scope/gray_launch_0_s0/RESET

Data Required Path:

AT | DELAY | TYPE | RF | FANOUT | LOC | NODE
10.000 | 10.000 | | | | | active clock edge time
10.000 | 0.000 | | | | | clk_sys
10.000 | 0.000 | tCL | FF | 1 | IOB117[B] | clk_ibuf/I
11.376 | 1.376 | tINS | FF | 17287 | IOB117[B] | clk_ibuf/O
14.207 | 2.831 | tNET | FF | 1 | R30C87[1][B] | u_hdmi/u_scope/gray_launch_0_s0/CLK
13.922 | -0.286 | tSu | | 1 | R30C87[1][B] | u_hdmi/u_scope/gray_launch_0_s0

Path Statistics:

Clock Skew | 0.057
Setup Relationship | 10.000
Logic Level | 1
Arrival Clock Path Delay | cell: 1.288, 31.042%; route: 2.862, 68.958%
Arrival Data Path Delay | cell: 0.000, 0.000%; route: 2.007, 85.359%; tC2Q: 0.344, 14.641%
Required Clock Path Delay | cell: 1.376, 32.714%; route: 2.831, 67.286%

### Path3

Path Summary:

Slack | 7.437
Data Arrival Time | 6.485
Data Required Time | 13.922
From | u_rst_sync/sync_chain_1_s0
To | u_hdmi/u_scope/mode_launch_s0
Launch Clk | clk_sys:[R]
Latch Clk | clk_sys:[F]

Data Arrival Path:

AT | DELAY | TYPE | RF | FANOUT | LOC | NODE
0.000 | 0.000 | | | | | active clock edge time
0.000 | 0.000 | | | | | clk_sys
0.000 | 0.000 | tCL | RR | 1 | IOB117[B] | clk_ibuf/I
1.288 | 1.288 | tINS | RR | 17287 | IOB117[B] | clk_ibuf/O
4.150 | 2.862 | tNET | RR | 1 | R73C55[1][A] | u_rst_sync/sync_chain_1_s0/CLK
4.495 | 0.344 | tC2Q | RR | 11918 | R73C55[1][A] | u_rst_sync/sync_chain_1_s0/Q
6.485 | 1.990 | tNET | RR | 1 | R30C89[1][B] | u_hdmi/u_scope/mode_launch_s0/RESET

Data Required Path:

AT | DELAY | TYPE | RF | FANOUT | LOC | NODE
10.000 | 10.000 | | | | | active clock edge time
10.000 | 0.000 | | | | | clk_sys
10.000 | 0.000 | tCL | FF | 1 | IOB117[B] | clk_ibuf/I
11.376 | 1.376 | tINS | FF | 17287 | IOB117[B] | clk_ibuf/O
14.207 | 2.831 | tNET | FF | 1 | R30C89[1][B] | u_hdmi/u_scope/mode_launch_s0/CLK
13.922 | -0.286 | tSu | | 1 | R30C89[1][B] | u_hdmi/u_scope/mode_launch_s0

Path Statistics:

Clock Skew | 0.057
Setup Relationship | 10.000
Logic Level | 1
Arrival Clock Path Delay | cell: 1.288, 31.042%; route: 2.862, 68.958%
Arrival Data Path Delay | cell: 0.000, 0.000%; route: 1.990, 85.253%; tC2Q: 0.344, 14.747%
Required Clock Path Delay | cell: 1.376, 32.714%; route: 2.831, 67.286%

### Path4

Path Summary:

Slack | 7.437
Data Arrival Time | 6.485
Data Required Time | 13.922
From | u_rst_sync/sync_chain_1_s0
To | u_hdmi/u_scope/gray_launch_7_s0
Launch Clk | clk_sys:[R]
Latch Clk | clk_sys:[F]

Data Arrival Path:

AT | DELAY | TYPE | RF | FANOUT | LOC | NODE
0.000 | 0.000 | | | | | active clock edge time
0.000 | 0.000 | | | | | clk_sys
0.000 | 0.000 | tCL | RR | 1 | IOB117[B] | clk_ibuf/I
1.288 | 1.288 | tINS | RR | 17287 | IOB117[B] | clk_ibuf/O
4.150 | 2.862 | tNET | RR | 1 | R73C55[1][A] | u_rst_sync/sync_chain_1_s0/CLK
4.495 | 0.344 | tC2Q | RR | 11918 | R73C55[1][A] | u_rst_sync/sync_chain_1_s0/Q
6.485 | 1.990 | tNET | RR | 1 | R30C89[0][A] | u_hdmi/u_scope/gray_launch_7_s0/RESET

Data Required Path:

AT | DELAY | TYPE | RF | FANOUT | LOC | NODE
10.000 | 10.000 | | | | | active clock edge time
10.000 | 0.000 | | | | | clk_sys
10.000 | 0.000 | tCL | FF | 1 | IOB117[B] | clk_ibuf/I
11.376 | 1.376 | tINS | FF | 17287 | IOB117[B] | clk_ibuf/O
14.207 | 2.831 | tNET | FF | 1 | R30C89[0][A] | u_hdmi/u_scope/gray_launch_7_s0/CLK
13.922 | -0.286 | tSu | | 1 | R30C89[0][A] | u_hdmi/u_scope/gray_launch_7_s0

Path Statistics:

Clock Skew | 0.057
Setup Relationship | 10.000
Logic Level | 1
Arrival Clock Path Delay | cell: 1.288, 31.042%; route: 2.862, 68.958%
Arrival Data Path Delay | cell: 0.000, 0.000%; route: 1.990, 85.253%; tC2Q: 0.344, 14.747%
Required Clock Path Delay | cell: 1.376, 32.714%; route: 2.831, 67.286%

### Path5

Path Summary:

Slack | 7.437
Data Arrival Time | 6.485
Data Required Time | 13.922
From | u_rst_sync/sync_chain_1_s0
To | u_hdmi/u_scope/gray_launch_8_s0
Launch Clk | clk_sys:[R]
Latch Clk | clk_sys:[F]

Data Arrival Path:

AT | DELAY | TYPE | RF | FANOUT | LOC | NODE
0.000 | 0.000 | | | | | active clock edge time
0.000 | 0.000 | | | | | clk_sys
0.000 | 0.000 | tCL | RR | 1 | IOB117[B] | clk_ibuf/I
1.288 | 1.288 | tINS | RR | 17287 | IOB117[B] | clk_ibuf/O
4.150 | 2.862 | tNET | RR | 1 | R73C55[1][A] | u_rst_sync/sync_chain_1_s0/CLK
4.495 | 0.344 | tC2Q | RR | 11918 | R73C55[1][A] | u_rst_sync/sync_chain_1_s0/Q
6.485 | 1.990 | tNET | RR | 1 | R30C89[0][B] | u_hdmi/u_scope/gray_launch_8_s0/RESET

Data Required Path:

AT | DELAY | TYPE | RF | FANOUT | LOC | NODE
10.000 | 10.000 | | | | | active clock edge time
10.000 | 0.000 | | | | | clk_sys
10.000 | 0.000 | tCL | FF | 1 | IOB117[B] | clk_ibuf/I
11.376 | 1.376 | tINS | FF | 17287 | IOB117[B] | clk_ibuf/O
14.207 | 2.831 | tNET | FF | 1 | R30C89[0][B] | u_hdmi/u_scope/gray_launch_8_s0/CLK
13.922 | -0.286 | tSu | | 1 | R30C89[0][B] | u_hdmi/u_scope/gray_launch_8_s0

Path Statistics:

Clock Skew | 0.057
Setup Relationship | 10.000
Logic Level | 1
Arrival Clock Path Delay | cell: 1.288, 31.042%; route: 2.862, 68.958%
Arrival Data Path Delay | cell: 0.000, 0.000%; route: 1.990, 85.253%; tC2Q: 0.344, 14.747%
Required Clock Path Delay | cell: 1.376, 32.714%; route: 2.831, 67.286%

### Hold Analysis Report

#### Report Command:report_exceptions -hold -max_paths 5 -max_common_paths 1

#### No timing exceptions to report!

### Recovery Analysis Report

#### Report Command:report_exceptions -recovery -max_paths 5 -max_common_paths 1

#### Timing Path Constraint[1]: set_max_delay -from [get_clocks {clk_sys}] -to [get_clocks {clk_sys}] 17.8

#### No timing paths to report!

#### Timing Path Constraint[2]: set_max_delay -from [get_clocks {clk_sys}] -to [get_regs {u_hdmi/u_scope/gray_launch_*_s0 u_hdmi/u_scope/full_launch_s0 u_hdmi/u_scope/mode_launch_s0}] 10.000

#### No timing paths to report!

### Removal Analysis Report

#### Report Command:report_exceptions -removal -max_paths 5 -max_common_paths 1

#### No timing exceptions to report!

## Timing Constraints Report:

SDC Command Type | State | Detail Command
TC_CLOCK | Actived | create_clock -name clk_sys -period 20 -waveform {0 10} [get_ports {clk}]
TC_GENERATED_CLOCK | Actived | create_generated_clock -name serial_clk -source [get_ports {clk}] -master_clock clk_sys -divide_by 8 -multiply_by 20 [get_pins {u_hdmi/u_clk/u_pll/CLKOUT0}]
TC_GENERATED_CLOCK | Actived | create_generated_clock -name pixel_clk -source [get_ports {clk}] -master_clock clk_sys -divide_by 40 -multiply_by 20 [get_pins {u_hdmi/u_clk/u_pll/CLKOUT1}]
TC_OUTPUT_DELAY | Actived | set_output_delay -clock clk_sys -max 2.0 [get_ports {HP_BCK}]
TC_OUTPUT_DELAY | Actived | set_output_delay -clock clk_sys -max 2.0 [get_ports {HP_WS}]
TC_OUTPUT_DELAY | Actived | set_output_delay -clock clk_sys -max 2.0 [get_ports {HP_DIN}]
TC_FALSE_PATH | Actived | set_false_path -to [get_ports {PA_EN_n}]
TC_FALSE_PATH | Actived | set_false_path -to [get_ports {led_heartbeat}]
TC_FALSE_PATH | Actived | set_false_path -from [get_ports {rst_n}]
TC_MAX_DELAY | Actived | set_max_delay -from [get_clocks {clk_sys}] -to [get_clocks {clk_sys}] 17.8
TC_MAX_DELAY | Actived | set_max_delay -from [get_clocks {clk_sys}] -to [get_regs {u_hdmi/u_scope/gray_launch_*_s0 u_hdmi/u_scope/full_launch_s0 u_hdmi/u_scope/mode_launch_s0}] 10.000
