hokuu1102/Gowin2026-PolySynth/evidence/q_adc_fix_20261012/before_timing.html

# Timing Messages

Report Title | Timing Analysis Report
Design File | C:\Users\cyx\Documents\ChatGPT\FPGA\Gowin2026-PolySynth-t31b-main\impl\gwsynthesis\Gowin2026.vg
Physical Constraints File | C:\Users\cyx\Documents\ChatGPT\FPGA\Gowin2026-PolySynth-t31b-main\constr\top.cst
Timing Constraint File | C:\Users\cyx\Documents\ChatGPT\FPGA\Gowin2026-PolySynth-t31b-main\constr\top.sdc
Tool Version | V1.9.12.03 (64-bit)
Part Number | GW5AT-LV60PG484AC1/I0
Device | GW5AT-60
Device Version | B
Created Time | Mon Oct 12 16:29:41 2026
Legal Announcement | Copyright (C)2014-2026 Gowin Semiconductor Corporation. All rights reserved.

# Timing Summaries

## STA Tool Run Summary:

Setup Delay Model | Slow 0.93V 0C C1/I0
Hold Delay Model | Fast 0.975V 85C C1/I0
Numbers of Paths Analyzed | 52053
Numbers of Endpoints Analyzed | 55513
Numbers of Falling Endpoints | 26
Numbers of Setup Violated Endpoints | 0
Numbers of Hold Violated Endpoints | 0

## Clock Summary:

NO. | Clock Name | Type | Period | Frequency(MHz) | Rise | Fall | Source | Master | Objects
1 | clk_sys | Base | 20.000 | 50.000 | 0.000 | 10.000 | | | clk
2 | serial_clk | Generated | 8.000 | 125.000 | 0.000 | 4.000 | clk | clk_sys | u_hdmi/u_clk/u_pll/CLKOUT0
3 | pixel_clk | Generated | 40.000 | 25.000 | 0.000 | 20.000 | clk | clk_sys | u_hdmi/u_clk/u_pll/CLKOUT1

## Max Frequency Summary:

NO. | Clock Name | Constraint | Actual Fmax | Logic Level | Entity
1 | clk_sys | 50.000(MHz) | 56.184(MHz) | 9 | TOP
2 | serial_clk | 125.000(MHz) | 1282.668(MHz) | 1 | TOP
3 | pixel_clk | 25.000(MHz) | 36.744(MHz) | 13 | TOP

## Total Negative Slack Summary:

Clock Name | Analysis Type | Endpoints TNS | Number of Endpoints
clk_sys | Setup | 0.000 | 0
clk_sys | Hold | 0.000 | 0
serial_clk | Setup | 0.000 | 0
serial_clk | Hold | 0.000 | 0
pixel_clk | Setup | 0.000 | 0
pixel_clk | Hold | 0.000 | 0

# Timing Details

## Path Slacks Table:

### Setup Paths Table

#### Report Command:report_timing -setup -max_paths 25 -max_common_paths 1

Path Number | Path Slack | From Node | To Node | From Clock | To Clock | Relation | Clock Skew | Data Delay
1 | 0.001 | g_sound.u_note_manager/fifo_ax_fifo_ax_0_0_s/DO[2] | g_sound.u_note_manager/same_idx_r_0_s0/CE | clk_sys:[R] | clk_sys:[R] | 17.800 | 0.008 | 17.510
2 | 0.059 | g_sound.u_note_manager/fifo_ax_fifo_ax_0_0_s/DO[2] | g_sound.u_note_manager/same_idx_r_1_s0/CE | clk_sys:[R] | clk_sys:[R] | 17.800 | 0.000 | 17.461
3 | 0.059 | g_sound.u_note_manager/fifo_ax_fifo_ax_0_0_s/DO[2] | g_sound.u_note_manager/same_idx_r_2_s0/CE | clk_sys:[R] | clk_sys:[R] | 17.800 | 0.000 | 17.461
4 | 0.506 | g_sound.u_note_manager/fifo_ax_fifo_ax_0_0_s/DO[2] | g_sound.u_note_manager/same_idx_r_3_s0/CE | clk_sys:[R] | clk_sys:[R] | 17.800 | 0.017 | 16.997
5 | 0.514 | g_sound.u_note_manager/fifo_ax_fifo_ax_0_0_s/DO[2] | g_sound.u_note_manager/same_idx_r_4_s0/CE | clk_sys:[R] | clk_sys:[R] | 17.800 | 0.008 | 16.997
6 | 1.250 | g_sound.u_note_manager/fifo_ax_fifo_ax_0_0_s/DO[2] | g_sound.u_note_manager/scan_cnt_1_s0/CE | clk_sys:[R] | clk_sys:[R] | 17.800 | 0.017 | 16.253
7 | 1.258 | g_sound.u_note_manager/fifo_ax_fifo_ax_0_0_s/DO[2] | g_sound.u_note_manager/scan_cnt_3_s0/CE | clk_sys:[R] | clk_sys:[R] | 17.800 | 0.008 | 16.253
8 | 1.378 | g_sound.u_envelope_bank/dec_r_0_s0/Q | g_sound.u_envelope_bank/env_level_o_57_s0/D | clk_sys:[R] | clk_sys:[R] | 17.800 | 0.000 | 16.364
9 | 1.436 | g_sound.u_note_manager/fifo_ax_fifo_ax_0_0_s/DO[2] | g_sound.u_note_manager/scan_cnt_2_s0/CE | clk_sys:[R] | clk_sys:[R] | 17.800 | 0.017 | 16.067
10 | 1.436 | g_sound.u_note_manager/fifo_ax_fifo_ax_0_0_s/DO[2] | g_sound.u_note_manager/scan_cnt_4_s0/CE | clk_sys:[R] | clk_sys:[R] | 17.800 | 0.017 | 16.067
11 | 1.708 | g_sound.u_note_manager/fifo_ax_fifo_ax_0_0_s/DO[2] | g_sound.u_note_manager/vtgt_vld_vtgt_vld_RAMREG_13_G[0]_s0/D | clk_sys:[R] | clk_sys:[R] | 17.800 | 0.008 | 16.026
12 | 1.712 | g_sound.u_envelope_bank/dec_r_0_s0/Q | g_sound.u_envelope_bank/env_level_o_9_s0/D | clk_sys:[R] | clk_sys:[R] | 17.800 | 0.008 | 16.022
13 | 1.713 | g_sound.u_note_manager/fifo_ax_fifo_ax_0_0_s/DO[2] | g_sound.u_note_manager/vtgt_vld_vtgt_vld_RAMREG_14_G[0]_s0/D | clk_sys:[R] | clk_sys:[R] | 17.800 | 0.017 | 16.013
14 | 1.776 | g_sound.u_note_manager/fifo_ax_fifo_ax_0_0_s/DO[2] | g_sound.u_note_manager/scan_cnt_0_s3/D | clk_sys:[R] | clk_sys:[R] | 17.800 | 0.017 | 15.950
15 | 1.801 | g_sound.u_note_manager/fifo_ax_fifo_ax_0_0_s/DO[2] | g_sound.u_note_manager/scan_sel_24_s0/D | clk_sys:[R] | clk_sys:[R] | 17.800 | 0.008 | 15.933
16 | 1.867 | g_sound.u_envelope_bank/dec_r_0_s0/Q | g_sound.u_envelope_bank/env_level_o_249_s0/D | clk_sys:[R] | clk_sys:[R] | 17.800 | 0.000 | 15.876
17 | 1.887 | g_sound.u_note_manager/fifo_ax_fifo_ax_0_0_s/DO[2] | g_sound.u_note_manager/vtgt_vld_vtgt_vld_RAMREG_12_G[0]_s0/D | clk_sys:[R] | clk_sys:[R] | 17.800 | 0.008 | 15.847
18 | 1.891 | g_sound.u_envelope_bank/dec_r_0_s0/Q | g_sound.u_envelope_bank/env_level_o_433_s0/D | clk_sys:[R] | clk_sys:[R] | 17.800 | -0.008 | 15.860
19 | 1.927 | g_sound.u_adc_farm/u_scan0/sample_channel_0_s0/Q | g_sound.u_calib1/n909_s/A[2] | clk_sys:[R] | clk_sys:[R] | 17.800 | 0.008 | 12.464
20 | 1.936 | g_sound.u_note_manager/fifo_ax_fifo_ax_0_0_s/DO[2] | g_sound.u_note_manager/scan_sel_25_s0/D | clk_sys:[R] | clk_sys:[R] | 17.800 | 0.008 | 15.798
21 | 1.958 | g_sound.u_note_manager/fifo_ax_fifo_ax_0_0_s/DO[2] | g_sound.u_note_manager/scan_sel_22_s0/D | clk_sys:[R] | clk_sys:[R] | 17.800 | 0.008 | 15.776
22 | 1.969 | g_sound.u_adc_farm/u_scan0/sample_channel_0_s0/Q | g_sound.u_calib1/n909_s/A[4] | clk_sys:[R] | clk_sys:[R] | 17.800 | 0.008 | 12.529
23 | 1.978 | g_sound.u_note_manager/fifo_ax_fifo_ax_0_0_s/DO[2] | g_sound.u_note_manager/scan_sel_26_s0/D | clk_sys:[R] | clk_sys:[R] | 17.800 | 0.008 | 15.756
24 | 1.978 | g_sound.u_note_manager/fifo_ax_fifo_ax_0_0_s/DO[2] | g_sound.u_note_manager/scan_sel_27_s0/D | clk_sys:[R] | clk_sys:[R] | 17.800 | 0.008 | 15.756
25 | 1.987 | g_sound.u_adc_farm/u_scan0/sample_channel_0_s0/Q | g_sound.u_calib1/n909_s/A[3] | clk_sys:[R] | clk_sys:[R] | 17.800 | 0.008 | 12.550

### Hold Paths Table

#### Report Command:report_timing -hold -max_paths 25 -max_common_paths 1

Path Number | Path Slack | From Node | To Node | From Clock | To Clock | Relation | Clock Skew | Data Delay
1 | 0.125 | u_rst_sync/sync_chain_1_s0/Q | u_hdmi/rstn_ser_0_s0/RESET | clk_sys:[R] | serial_clk:[R] | 0.000 | -0.923 | 0.999
2 | 0.130 | u_hdmi/u_blue/symbol_6_s0/Q | u_hdmi/u_serializer/lanes[0].u_oser/D6 | pixel_clk:[R] | pixel_clk:[R] | 0.000 | 0.000 | 0.215
3 | 0.130 | u_hdmi/u_blue/symbol_7_s0/Q | u_hdmi/u_serializer/lanes[0].u_oser/D0 | pixel_clk:[R] | pixel_clk:[R] | 0.000 | 0.000 | 0.215
4 | 0.198 | g_sound.demo_note_inc_25_s0/Q | g_sound.u_seq_arb/mem_mem_RAMREG_3_G[35]_s0/D | clk_sys:[R] | clk_sys:[R] | 0.000 | -0.185 | 0.405
5 | 0.201 | u_hdmi/u_blue/symbol_4_s0/Q | u_hdmi/u_serializer/lanes[0].u_oser/D4 | pixel_clk:[R] | pixel_clk:[R] | 0.000 | 0.000 | 0.286
6 | 0.202 | g_sound.demo_note_inc_25_s0/Q | g_sound.u_seq_arb/mem_mem_RAMREG_5_G[35]_s0/D | clk_sys:[R] | clk_sys:[R] | 0.000 | -0.181 | 0.405
7 | 0.212 | u_hdmi/u_blue/symbol_3_s0/Q | u_hdmi/u_serializer/lanes[0].u_oser/D3 | pixel_clk:[R] | pixel_clk:[R] | 0.000 | 0.000 | 0.286
8 | 0.216 | u_hdmi/u_blue/symbol_6_s0/Q | u_hdmi/u_serializer/lanes[0].u_oser/D2 | pixel_clk:[R] | pixel_clk:[R] | 0.000 | 0.000 | 0.301
9 | 0.225 | u_hdmi/u_blue/symbol_9_s0/Q | u_hdmi/u_serializer/lanes[0].u_oser/D9 | pixel_clk:[R] | pixel_clk:[R] | 0.000 | 0.000 | 0.300
10 | 0.247 | u_led_indicator/beat_t_9_s1/Q | u_led_indicator/beat_t_9_s1/D | clk_sys:[R] | clk_sys:[R] | 0.000 | 0.000 | 0.270
11 | 0.247 | u_ws2812/led_i_0_s1/Q | u_ws2812/led_i_0_s1/D | clk_sys:[R] | clk_sys:[R] | 0.000 | 0.000 | 0.270
12 | 0.247 | u_ws2812/led_i_1_s1/Q | u_ws2812/led_i_1_s1/D | clk_sys:[R] | clk_sys:[R] | 0.000 | 0.000 | 0.270
13 | 0.247 | u_i2s_tx_ext/ch_s0/Q | u_i2s_tx_ext/ch_s0/D | clk_sys:[R] | clk_sys:[R] | 0.000 | 0.000 | 0.270
14 | 0.247 | u_i2s_tx/ch_s0/Q | u_i2s_tx/ch_s0/D | clk_sys:[R] | clk_sys:[R] | 0.000 | 0.000 | 0.270
15 | 0.247 | u_i2s_tx/bit_cnt_3_s0/Q | u_i2s_tx/bit_cnt_3_s0/D | clk_sys:[R] | clk_sys:[R] | 0.000 | 0.000 | 0.270
16 | 0.247 | g_sound.u_tdm_render_mixer/cnt_0_s2/Q | g_sound.u_tdm_render_mixer/cnt_0_s2/D | clk_sys:[R] | clk_sys:[R] | 0.000 | 0.000 | 0.270
17 | 0.247 | g_sound.u_perc_env_bank/gen_perc[4].level_r_0_s0/Q | g_sound.u_perc_env_bank/gen_perc[4].level_r_0_s0/D | clk_sys:[R] | clk_sys:[R] | 0.000 | 0.000 | 0.270
18 | 0.247 | g_sound.u_perc_env_bank/gen_perc[4].level_r_5_s0/Q | g_sound.u_perc_env_bank/gen_perc[4].level_r_5_s0/D | clk_sys:[R] | clk_sys:[R] | 0.000 | 0.000 | 0.270
19 | 0.247 | g_sound.u_perc_env_bank/gen_perc[3].level_r_7_s0/Q | g_sound.u_perc_env_bank/gen_perc[3].level_r_7_s0/D | clk_sys:[R] | clk_sys:[R] | 0.000 | 0.000 | 0.270
20 | 0.247 | g_sound.u_perc_env_bank/gen_perc[0].level_r_1_s0/Q | g_sound.u_perc_env_bank/gen_perc[0].level_r_1_s0/D | clk_sys:[R] | clk_sys:[R] | 0.000 | 0.000 | 0.270
21 | 0.247 | g_sound.u_vibrato_lfo/slew_count_q_3_s0/Q | g_sound.u_vibrato_lfo/slew_count_q_3_s0/D | clk_sys:[R] | clk_sys:[R] | 0.000 | 0.000 | 0.270
22 | 0.247 | g_sound.u_vibrato_lfo/slew_count_q_12_s0/Q | g_sound.u_vibrato_lfo/slew_count_q_12_s0/D | clk_sys:[R] | clk_sys:[R] | 0.000 | 0.000 | 0.270
23 | 0.247 | g_sound.u_vibrato_lfo/slew_count_q_16_s0/Q | g_sound.u_vibrato_lfo/slew_count_q_16_s0/D | clk_sys:[R] | clk_sys:[R] | 0.000 | 0.000 | 0.270
24 | 0.247 | g_sound.u_vibrato_lfo/slew_count_q_21_s0/Q | g_sound.u_vibrato_lfo/slew_count_q_21_s0/D | clk_sys:[R] | clk_sys:[R] | 0.000 | 0.000 | 0.270
25 | 0.247 | g_sound.u_vibrato_lfo/slew_count_q_25_s0/Q | g_sound.u_vibrato_lfo/slew_count_q_25_s0/D | clk_sys:[R] | clk_sys:[R] | 0.000 | 0.000 | 0.270

### Recovery Paths Table

#### Report Command:report_timing -recovery -max_paths 25 -max_common_paths 1

Path Number | Path Slack | From Node | To Node | From Clock | To Clock | Relation | Clock Skew | Data Delay
1 | 0.158 | u_hdmi/rstn_ser_2_s0/Q | u_hdmi/u_serializer/lanes[1].u_oser/RESET | serial_clk:[R] | serial_clk:[F] | 4.000 | 2.671 | 1.035
2 | 0.159 | u_hdmi/rstn_ser_2_s0/Q | u_hdmi/u_serializer/lanes[2].u_oser/RESET | serial_clk:[R] | serial_clk:[F] | 4.000 | 2.671 | 1.034
3 | 0.273 | u_hdmi/rstn_ser_2_s0/Q | u_hdmi/u_serializer/lanes[0].u_oser/RESET | serial_clk:[R] | serial_clk:[F] | 4.000 | 2.671 | 0.920
4 | 0.299 | u_hdmi/rstn_ser_2_s0/Q | u_hdmi/u_serializer/lanes[3].u_oser/RESET | serial_clk:[R] | serial_clk:[F] | 4.000 | 2.671 | 0.894
5 | 4.157 | u_hdmi/rstn_ser_2_s0/Q | u_hdmi/u_serializer/lanes[1].u_oser/RESET | serial_clk:[R] | serial_clk:[R] | 8.000 | 2.671 | 1.035
6 | 4.158 | u_hdmi/rstn_ser_2_s0/Q | u_hdmi/u_serializer/lanes[2].u_oser/RESET | serial_clk:[R] | serial_clk:[R] | 8.000 | 2.671 | 1.034
7 | 4.271 | u_hdmi/rstn_ser_2_s0/Q | u_hdmi/u_serializer/lanes[0].u_oser/RESET | serial_clk:[R] | serial_clk:[R] | 8.000 | 2.671 | 0.920
8 | 4.297 | u_hdmi/rstn_ser_2_s0/Q | u_hdmi/u_serializer/lanes[3].u_oser/RESET | serial_clk:[R] | serial_clk:[R] | 8.000 | 2.671 | 0.894
9 | 6.003 | u_hdmi/rstn_ser_2_s0/Q | u_hdmi/u_serializer/lanes[1].u_oser/RESET | serial_clk:[R] | pixel_clk:[R] | 8.000 | 0.790 | 1.035
10 | 6.004 | u_hdmi/rstn_ser_2_s0/Q | u_hdmi/u_serializer/lanes[2].u_oser/RESET | serial_clk:[R] | pixel_clk:[R] | 8.000 | 0.790 | 1.034
11 | 6.117 | u_hdmi/rstn_ser_2_s0/Q | u_hdmi/u_serializer/lanes[0].u_oser/RESET | serial_clk:[R] | pixel_clk:[R] | 8.000 | 0.790 | 0.920
12 | 6.143 | u_hdmi/rstn_ser_2_s0/Q | u_hdmi/u_serializer/lanes[3].u_oser/RESET | serial_clk:[R] | pixel_clk:[R] | 8.000 | 0.790 | 0.894

### Removal Paths Table

#### Report Command:report_timing -removal -max_paths 25 -max_common_paths 1

Path Number | Path Slack | From Node | To Node | From Clock | To Clock | Relation | Clock Skew | Data Delay
1 | 0.488 | u_hdmi/rstn_ser_2_s0/Q | u_hdmi/u_serializer/lanes[3].u_oser/RESET | serial_clk:[R] | pixel_clk:[R] | 0.000 | 0.325 | 0.336
2 | 0.501 | u_hdmi/rstn_ser_2_s0/Q | u_hdmi/u_serializer/lanes[2].u_oser/RESET | serial_clk:[R] | pixel_clk:[R] | 0.000 | 0.325 | 0.349
3 | 0.501 | u_hdmi/rstn_ser_2_s0/Q | u_hdmi/u_serializer/lanes[0].u_oser/RESET | serial_clk:[R] | pixel_clk:[R] | 0.000 | 0.325 | 0.349
4 | 0.569 | u_hdmi/rstn_ser_2_s0/Q | u_hdmi/u_serializer/lanes[1].u_oser/RESET | serial_clk:[R] | pixel_clk:[R] | 0.000 | 0.325 | 0.417
5 | 1.125 | u_hdmi/rstn_ser_2_s0/Q | u_hdmi/u_serializer/lanes[3].u_oser/RESET | serial_clk:[R] | serial_clk:[R] | 0.000 | 0.927 | 0.336
6 | 1.138 | u_hdmi/rstn_ser_2_s0/Q | u_hdmi/u_serializer/lanes[0].u_oser/RESET | serial_clk:[R] | serial_clk:[R] | 0.000 | 0.927 | 0.349
7 | 1.138 | u_hdmi/rstn_ser_2_s0/Q | u_hdmi/u_serializer/lanes[2].u_oser/RESET | serial_clk:[R] | serial_clk:[R] | 0.000 | 0.927 | 0.349
8 | 1.206 | u_hdmi/rstn_ser_2_s0/Q | u_hdmi/u_serializer/lanes[1].u_oser/RESET | serial_clk:[R] | serial_clk:[R] | 0.000 | 0.927 | 0.417
9 | 5.127 | u_hdmi/rstn_ser_2_s0/Q | u_hdmi/u_serializer/lanes[3].u_oser/RESET | serial_clk:[R] | serial_clk:[F] | -4.000 | 0.927 | 0.336
10 | 5.140 | u_hdmi/rstn_ser_2_s0/Q | u_hdmi/u_serializer/lanes[0].u_oser/RESET | serial_clk:[R] | serial_clk:[F] | -4.000 | 0.927 | 0.349
11 | 5.140 | u_hdmi/rstn_ser_2_s0/Q | u_hdmi/u_serializer/lanes[2].u_oser/RESET | serial_clk:[R] | serial_clk:[F] | -4.000 | 0.927 | 0.349
12 | 5.208 | u_hdmi/rstn_ser_2_s0/Q | u_hdmi/u_serializer/lanes[1].u_oser/RESET | serial_clk:[R] | serial_clk:[F] | -4.000 | 0.927 | 0.417

## Minimum Pulse Width Table:

Number | Slack | Actual Width | Required Width | Type | Clock | Objects

#### Report Command:report_min_pulse_width -nworst 10 -detail

1 | 0.087 | 0.312 | 0.225 | Low Pulse Width | serial_clk | u_hdmi/rstn_ser_2_s0
2 | 0.087 | 0.312 | 0.225 | Low Pulse Width | serial_clk | u_hdmi/rstn_ser_1_s0
3 | 0.087 | 0.312 | 0.225 | Low Pulse Width | serial_clk | u_hdmi/rstn_ser_0_s0
4 | 0.088 | 0.313 | 0.225 | High Pulse Width | serial_clk | u_hdmi/rstn_ser_2_s0
5 | 0.088 | 0.313 | 0.225 | High Pulse Width | serial_clk | u_hdmi/rstn_ser_1_s0
6 | 0.088 | 0.313 | 0.225 | High Pulse Width | serial_clk | u_hdmi/rstn_ser_0_s0
7 | 6.809 | 7.709 | 0.900 | Low Pulse Width | clk_sys | g_sound.u_looper/ep_mem_ep_mem_0_1_s
8 | 6.814 | 7.714 | 0.900 | Low Pulse Width | clk_sys | g_sound.u_looper/ep_mem_ep_mem_0_1_s
9 | 6.814 | 7.714 | 0.900 | Low Pulse Width | clk_sys | g_sound.u_looper/ep_mem_ep_mem_0_2_s
10 | 6.814 | 7.714 | 0.900 | Low Pulse Width | clk_sys | g_sound.u_looper/ep_mem_ep_mem_0_3_s

## Timing Report By Analysis Type:

### Setup Analysis Report

#### Report Command:report_timing -setup -max_paths 25 -max_common_paths 1

### Path1

Path Summary:

Slack | 0.001
Data Arrival Time | 21.660
Data Required Time | 21.662
From | g_sound.u_note_manager/fifo_ax_fifo_ax_0_0_s
To | g_sound.u_note_manager/same_idx_r_0_s0
Launch Clk | clk_sys:[R]
Latch Clk | clk_sys:[R]

Data Arrival Path:

AT | DELAY | TYPE | RF | FANOUT | LOC | NODE
0.000 | 0.000 | | | | | active clock edge time
0.000 | 0.000 | | | | | clk_sys
0.000 | 0.000 | tCL | RR | 1 | IOB117[B] | clk_ibuf/I
1.288 | 1.288 | tINS | RR | 17271 | IOB117[B] | clk_ibuf/O
4.150 | 2.862 | tNET | RR | 16 | BSRAM_R56[11][A] | g_sound.u_note_manager/fifo_ax_fifo_ax_0_0_s/CLKB
5.959 | 1.809 | tC2Q | RR | 35 | BSRAM_R56[11][A] | g_sound.u_note_manager/fifo_ax_fifo_ax_0_0_s/DO[2]
8.563 | 2.604 | tNET | RR | 2 | R71C55[1][A] | g_sound.u_note_manager/n1777_s0/I1
9.069 | 0.506 | tINS | RF | 1 | R71C55[1][A] | g_sound.u_note_manager/n1777_s0/COUT
9.069 | 0.000 | tNET | FF | 2 | R71C55[1][B] | g_sound.u_note_manager/n1778_s0/CIN
9.114 | 0.045 | tINS | FR | 2 | R71C55[1][B] | g_sound.u_note_manager/n1778_s0/COUT
11.406 | 2.292 | tNET | RR | 1 | R37C70[3][B] | g_sound.u_note_manager/same_valid_s24/I3
11.875 | 0.469 | tINS | RR | 3 | R37C70[3][B] | g_sound.u_note_manager/same_valid_s24/F
13.024 | 1.149 | tNET | RR | 1 | R25C89[2][B] | g_sound.u_note_manager/same_valid_s11/I1
13.439 | 0.415 | tINS | RR | 3 | R25C89[2][B] | g_sound.u_note_manager/same_valid_s11/F
13.756 | 0.317 | tNET | RR | 1 | R24C90[2][A] | g_sound.u_note_manager/same_valid_s4/I0
14.221 | 0.465 | tINS | RR | 2 | R24C90[2][A] | g_sound.u_note_manager/same_valid_s4/F
14.365 | 0.144 | tNET | RR | 1 | R25C90[3][B] | g_sound.u_note_manager/same_valid_s0/I3
14.738 | 0.373 | tINS | RR | 4 | R25C90[3][B] | g_sound.u_note_manager/same_valid_s0/F
17.236 | 2.497 | tNET | RR | 1 | R61C58[3][A] | g_sound.u_note_manager/n26787_s5/I2
17.497 | 0.261 | tINS | RF | 3 | R61C58[3][A] | g_sound.u_note_manager/n26787_s5/F
17.510 | 0.014 | tNET | FF | 1 | R61C58[3][B] | g_sound.u_note_manager/n26787_s6/I3
17.884 | 0.373 | tINS | FR | 5 | R61C58[3][B] | g_sound.u_note_manager/n26787_s6/F
21.660 | 3.777 | tNET | RR | 1 | R25C91[2][B] | g_sound.u_note_manager/same_idx_r_0_s0/CE

Data Required Path:

AT | DELAY | TYPE | RF | FANOUT | LOC | NODE
17.800 | 17.800 | | | | | active clock edge time
17.800 | 0.000 | | | | | clk_sys
17.800 | 0.000 | tCL | RR | 1 | IOB117[B] | clk_ibuf/I
19.088 | 1.288 | tINS | RR | 17271 | IOB117[B] | clk_ibuf/O
21.942 | 2.854 | tNET | RR | 1 | R25C91[2][B] | g_sound.u_note_manager/same_idx_r_0_s0/CLK
21.662 | -0.280 | tSu | | 1 | R25C91[2][B] | g_sound.u_note_manager/same_idx_r_0_s0

Path Statistics:

Clock Skew | -0.008
Setup Relationship | 17.800
Logic Level | 9
Arrival Clock Path Delay | cell: 1.288, 31.042%; route: 2.862, 68.958%
Arrival Data Path Delay | cell: 2.908, 16.608%; route: 12.793, 73.060%; tC2Q: 1.809, 10.331%
Required Clock Path Delay | cell: 1.288, 31.105%; route: 2.854, 68.895%

### Path2

Path Summary:

Slack | 0.059
Data Arrival Time | 21.611
Data Required Time | 21.670
From | g_sound.u_note_manager/fifo_ax_fifo_ax_0_0_s
To | g_sound.u_note_manager/same_idx_r_1_s0
Launch Clk | clk_sys:[R]
Latch Clk | clk_sys:[R]

Data Arrival Path:

AT | DELAY | TYPE | RF | FANOUT | LOC | NODE
0.000 | 0.000 | | | | | active clock edge time
0.000 | 0.000 | | | | | clk_sys
0.000 | 0.000 | tCL | RR | 1 | IOB117[B] | clk_ibuf/I
1.288 | 1.288 | tINS | RR | 17271 | IOB117[B] | clk_ibuf/O
4.150 | 2.862 | tNET | RR | 16 | BSRAM_R56[11][A] | g_sound.u_note_manager/fifo_ax_fifo_ax_0_0_s/CLKB
5.959 | 1.809 | tC2Q | RR | 35 | BSRAM_R56[11][A] | g_sound.u_note_manager/fifo_ax_fifo_ax_0_0_s/DO[2]
8.563 | 2.604 | tNET | RR | 2 | R71C55[1][A] | g_sound.u_note_manager/n1777_s0/I1
9.069 | 0.506 | tINS | RF | 1 | R71C55[1][A] | g_sound.u_note_manager/n1777_s0/COUT
9.069 | 0.000 | tNET | FF | 2 | R71C55[1][B] | g_sound.u_note_manager/n1778_s0/CIN
9.114 | 0.045 | tINS | FR | 2 | R71C55[1][B] | g_sound.u_note_manager/n1778_s0/COUT
11.406 | 2.292 | tNET | RR | 1 | R37C70[3][B] | g_sound.u_note_manager/same_valid_s24/I3
11.875 | 0.469 | tINS | RR | 3 | R37C70[3][B] | g_sound.u_note_manager/same_valid_s24/F
13.024 | 1.149 | tNET | RR | 1 | R25C89[2][B] | g_sound.u_note_manager/same_valid_s11/I1
13.439 | 0.415 | tINS | RR | 3 | R25C89[2][B] | g_sound.u_note_manager/same_valid_s11/F
13.756 | 0.317 | tNET | RR | 1 | R24C90[2][A] | g_sound.u_note_manager/same_valid_s4/I0
14.221 | 0.465 | tINS | RR | 2 | R24C90[2][A] | g_sound.u_note_manager/same_valid_s4/F
14.365 | 0.144 | tNET | RR | 1 | R25C90[3][B] | g_sound.u_note_manager/same_valid_s0/I3
14.738 | 0.373 | tINS | RR | 4 | R25C90[3][B] | g_sound.u_note_manager/same_valid_s0/F
17.236 | 2.497 | tNET | RR | 1 | R61C58[3][A] | g_sound.u_note_manager/n26787_s5/I2
17.497 | 0.261 | tINS | RF | 3 | R61C58[3][A] | g_sound.u_note_manager/n26787_s5/F
17.510 | 0.014 | tNET | FF | 1 | R61C58[3][B] | g_sound.u_note_manager/n26787_s6/I3
17.884 | 0.373 | tINS | FR | 5 | R61C58[3][B] | g_sound.u_note_manager/n26787_s6/F
21.611 | 3.727 | tNET | RR | 1 | R25C92[2][B] | g_sound.u_note_manager/same_idx_r_1_s0/CE

Data Required Path:

AT | DELAY | TYPE | RF | FANOUT | LOC | NODE
17.800 | 17.800 | | | | | active clock edge time
17.800 | 0.000 | | | | | clk_sys
17.800 | 0.000 | tCL | RR | 1 | IOB117[B] | clk_ibuf/I
19.088 | 1.288 | tINS | RR | 17271 | IOB117[B] | clk_ibuf/O
21.950 | 2.862 | tNET | RR | 1 | R25C92[2][B] | g_sound.u_note_manager/same_idx_r_1_s0/CLK
21.670 | -0.280 | tSu | | 1 | R25C92[2][B] | g_sound.u_note_manager/same_idx_r_1_s0

Path Statistics:

Clock Skew | 0.000
Setup Relationship | 17.800
Logic Level | 9
Arrival Clock Path Delay | cell: 1.288, 31.042%; route: 2.862, 68.958%
Arrival Data Path Delay | cell: 2.908, 16.655%; route: 12.743, 72.984%; tC2Q: 1.809, 10.360%
Required Clock Path Delay | cell: 1.288, 31.042%; route: 2.862, 68.958%

### Path3

Path Summary:

Slack | 0.059
Data Arrival Time | 21.611
Data Required Time | 21.670
From | g_sound.u_note_manager/fifo_ax_fifo_ax_0_0_s
To | g_sound.u_note_manager/same_idx_r_2_s0
Launch Clk | clk_sys:[R]
Latch Clk | clk_sys:[R]

Data Arrival Path:

AT | DELAY | TYPE | RF | FANOUT | LOC | NODE
0.000 | 0.000 | | | | | active clock edge time
0.000 | 0.000 | | | | | clk_sys
0.000 | 0.000 | tCL | RR | 1 | IOB117[B] | clk_ibuf/I
1.288 | 1.288 | tINS | RR | 17271 | IOB117[B] | clk_ibuf/O
4.150 | 2.862 | tNET | RR | 16 | BSRAM_R56[11][A] | g_sound.u_note_manager/fifo_ax_fifo_ax_0_0_s/CLKB
5.959 | 1.809 | tC2Q | RR | 35 | BSRAM_R56[11][A] | g_sound.u_note_manager/fifo_ax_fifo_ax_0_0_s/DO[2]
8.563 | 2.604 | tNET | RR | 2 | R71C55[1][A] | g_sound.u_note_manager/n1777_s0/I1
9.069 | 0.506 | tINS | RF | 1 | R71C55[1][A] | g_sound.u_note_manager/n1777_s0/COUT
9.069 | 0.000 | tNET | FF | 2 | R71C55[1][B] | g_sound.u_note_manager/n1778_s0/CIN
9.114 | 0.045 | tINS | FR | 2 | R71C55[1][B] | g_sound.u_note_manager/n1778_s0/COUT
11.406 | 2.292 | tNET | RR | 1 | R37C70[3][B] | g_sound.u_note_manager/same_valid_s24/I3
11.875 | 0.469 | tINS | RR | 3 | R37C70[3][B] | g_sound.u_note_manager/same_valid_s24/F
13.024 | 1.149 | tNET | RR | 1 | R25C89[2][B] | g_sound.u_note_manager/same_valid_s11/I1
13.439 | 0.415 | tINS | RR | 3 | R25C89[2][B] | g_sound.u_note_manager/same_valid_s11/F
13.756 | 0.317 | tNET | RR | 1 | R24C90[2][A] | g_sound.u_note_manager/same_valid_s4/I0
14.221 | 0.465 | tINS | RR | 2 | R24C90[2][A] | g_sound.u_note_manager/same_valid_s4/F
14.365 | 0.144 | tNET | RR | 1 | R25C90[3][B] | g_sound.u_note_manager/same_valid_s0/I3
14.738 | 0.373 | tINS | RR | 4 | R25C90[3][B] | g_sound.u_note_manager/same_valid_s0/F
17.236 | 2.497 | tNET | RR | 1 | R61C58[3][A] | g_sound.u_note_manager/n26787_s5/I2
17.497 | 0.261 | tINS | RF | 3 | R61C58[3][A] | g_sound.u_note_manager/n26787_s5/F
17.510 | 0.014 | tNET | FF | 1 | R61C58[3][B] | g_sound.u_note_manager/n26787_s6/I3
17.884 | 0.373 | tINS | FR | 5 | R61C58[3][B] | g_sound.u_note_manager/n26787_s6/F
21.611 | 3.727 | tNET | RR | 1 | R25C92[0][B] | g_sound.u_note_manager/same_idx_r_2_s0/CE

Data Required Path:

AT | DELAY | TYPE | RF | FANOUT | LOC | NODE
17.800 | 17.800 | | | | | active clock edge time
17.800 | 0.000 | | | | | clk_sys
17.800 | 0.000 | tCL | RR | 1 | IOB117[B] | clk_ibuf/I
19.088 | 1.288 | tINS | RR | 17271 | IOB117[B] | clk_ibuf/O
21.950 | 2.862 | tNET | RR | 1 | R25C92[0][B] | g_sound.u_note_manager/same_idx_r_2_s0/CLK
21.670 | -0.280 | tSu | | 1 | R25C92[0][B] | g_sound.u_note_manager/same_idx_r_2_s0

Path Statistics:

Clock Skew | 0.000
Setup Relationship | 17.800
Logic Level | 9
Arrival Clock Path Delay | cell: 1.288, 31.042%; route: 2.862, 68.958%
Arrival Data Path Delay | cell: 2.908, 16.655%; route: 12.743, 72.984%; tC2Q: 1.809, 10.360%
Required Clock Path Delay | cell: 1.288, 31.042%; route: 2.862, 68.958%

### Path4

Path Summary:

Slack | 0.506
Data Arrival Time | 21.147
Data Required Time | 21.653
From | g_sound.u_note_manager/fifo_ax_fifo_ax_0_0_s
To | g_sound.u_note_manager/same_idx_r_3_s0
Launch Clk | clk_sys:[R]
Latch Clk | clk_sys:[R]

Data Arrival Path:

AT | DELAY | TYPE | RF | FANOUT | LOC | NODE
0.000 | 0.000 | | | | | active clock edge time
0.000 | 0.000 | | | | | clk_sys
0.000 | 0.000 | tCL | RR | 1 | IOB117[B] | clk_ibuf/I
1.288 | 1.288 | tINS | RR | 17271 | IOB117[B] | clk_ibuf/O
4.150 | 2.862 | tNET | RR | 16 | BSRAM_R56[11][A] | g_sound.u_note_manager/fifo_ax_fifo_ax_0_0_s/CLKB
5.959 | 1.809 | tC2Q | RR | 35 | BSRAM_R56[11][A] | g_sound.u_note_manager/fifo_ax_fifo_ax_0_0_s/DO[2]
8.563 | 2.604 | tNET | RR | 2 | R71C55[1][A] | g_sound.u_note_manager/n1777_s0/I1
9.069 | 0.506 | tINS | RF | 1 | R71C55[1][A] | g_sound.u_note_manager/n1777_s0/COUT
9.069 | 0.000 | tNET | FF | 2 | R71C55[1][B] | g_sound.u_note_manager/n1778_s0/CIN
9.114 | 0.045 | tINS | FR | 2 | R71C55[1][B] | g_sound.u_note_manager/n1778_s0/COUT
11.406 | 2.292 | tNET | RR | 1 | R37C70[3][B] | g_sound.u_note_manager/same_valid_s24/I3
11.875 | 0.469 | tINS | RR | 3 | R37C70[3][B] | g_sound.u_note_manager/same_valid_s24/F
13.024 | 1.149 | tNET | RR | 1 | R25C89[2][B] | g_sound.u_note_manager/same_valid_s11/I1
13.439 | 0.415 | tINS | RR | 3 | R25C89[2][B] | g_sound.u_note_manager/same_valid_s11/F
13.756 | 0.317 | tNET | RR | 1 | R24C90[2][A] | g_sound.u_note_manager/same_valid_s4/I0
14.221 | 0.465 | tINS | RR | 2 | R24C90[2][A] | g_sound.u_note_manager/same_valid_s4/F
14.365 | 0.144 | tNET | RR | 1 | R25C90[3][B] | g_sound.u_note_manager/same_valid_s0/I3
14.738 | 0.373 | tINS | RR | 4 | R25C90[3][B] | g_sound.u_note_manager/same_valid_s0/F
17.236 | 2.497 | tNET | RR | 1 | R61C58[3][A] | g_sound.u_note_manager/n26787_s5/I2
17.497 | 0.261 | tINS | RF | 3 | R61C58[3][A] | g_sound.u_note_manager/n26787_s5/F
17.510 | 0.014 | tNET | FF | 1 | R61C58[3][B] | g_sound.u_note_manager/n26787_s6/I3
17.884 | 0.373 | tINS | FR | 5 | R61C58[3][B] | g_sound.u_note_manager/n26787_s6/F
21.147 | 3.264 | tNET | RR | 1 | R25C90[0][A] | g_sound.u_note_manager/same_idx_r_3_s0/CE

Data Required Path:

AT | DELAY | TYPE | RF | FANOUT | LOC | NODE
17.800 | 17.800 | | | | | active clock edge time
17.800 | 0.000 | | | | | clk_sys
17.800 | 0.000 | tCL | RR | 1 | IOB117[B] | clk_ibuf/I
19.088 | 1.288 | tINS | RR | 17271 | IOB117[B] | clk_ibuf/O
21.933 | 2.845 | tNET | RR | 1 | R25C90[0][A] | g_sound.u_note_manager/same_idx_r_3_s0/CLK
21.653 | -0.280 | tSu | | 1 | R25C90[0][A] | g_sound.u_note_manager/same_idx_r_3_s0

Path Statistics:

Clock Skew | -0.017
Setup Relationship | 17.800
Logic Level | 9
Arrival Clock Path Delay | cell: 1.288, 31.042%; route: 2.862, 68.958%
Arrival Data Path Delay | cell: 2.908, 17.110%; route: 12.280, 72.247%; tC2Q: 1.809, 10.643%
Required Clock Path Delay | cell: 1.288, 31.169%; route: 2.845, 68.831%

### Path5

Path Summary:

Slack | 0.514
Data Arrival Time | 21.147
Data Required Time | 21.662
From | g_sound.u_note_manager/fifo_ax_fifo_ax_0_0_s
To | g_sound.u_note_manager/same_idx_r_4_s0
Launch Clk | clk_sys:[R]
Latch Clk | clk_sys:[R]

Data Arrival Path:

AT | DELAY | TYPE | RF | FANOUT | LOC | NODE
0.000 | 0.000 | | | | | active clock edge time
0.000 | 0.000 | | | | | clk_sys
0.000 | 0.000 | tCL | RR | 1 | IOB117[B] | clk_ibuf/I
1.288 | 1.288 | tINS | RR | 17271 | IOB117[B] | clk_ibuf/O
4.150 | 2.862 | tNET | RR | 16 | BSRAM_R56[11][A] | g_sound.u_note_manager/fifo_ax_fifo_ax_0_0_s/CLKB
5.959 | 1.809 | tC2Q | RR | 35 | BSRAM_R56[11][A] | g_sound.u_note_manager/fifo_ax_fifo_ax_0_0_s/DO[2]
8.563 | 2.604 | tNET | RR | 2 | R71C55[1][A] | g_sound.u_note_manager/n1777_s0/I1
9.069 | 0.506 | tINS | RF | 1 | R71C55[1][A] | g_sound.u_note_manager/n1777_s0/COUT
9.069 | 0.000 | tNET | FF | 2 | R71C55[1][B] | g_sound.u_note_manager/n1778_s0/CIN
9.114 | 0.045 | tINS | FR | 2 | R71C55[1][B] | g_sound.u_note_manager/n1778_s0/COUT
11.406 | 2.292 | tNET | RR | 1 | R37C70[3][B] | g_sound.u_note_manager/same_valid_s24/I3
11.875 | 0.469 | tINS | RR | 3 | R37C70[3][B] | g_sound.u_note_manager/same_valid_s24/F
13.024 | 1.149 | tNET | RR | 1 | R25C89[2][B] | g_sound.u_note_manager/same_valid_s11/I1
13.439 | 0.415 | tINS | RR | 3 | R25C89[2][B] | g_sound.u_note_manager/same_valid_s11/F
13.756 | 0.317 | tNET | RR | 1 | R24C90[2][A] | g_sound.u_note_manager/same_valid_s4/I0
14.221 | 0.465 | tINS | RR | 2 | R24C90[2][A] | g_sound.u_note_manager/same_valid_s4/F
14.365 | 0.144 | tNET | RR | 1 | R25C90[3][B] | g_sound.u_note_manager/same_valid_s0/I3
14.738 | 0.373 | tINS | RR | 4 | R25C90[3][B] | g_sound.u_note_manager/same_valid_s0/F
17.236 | 2.497 | tNET | RR | 1 | R61C58[3][A] | g_sound.u_note_manager/n26787_s5/I2
17.497 | 0.261 | tINS | RF | 3 | R61C58[3][A] | g_sound.u_note_manager/n26787_s5/F
17.510 | 0.014 | tNET | FF | 1 | R61C58[3][B] | g_sound.u_note_manager/n26787_s6/I3
17.884 | 0.373 | tINS | FR | 5 | R61C58[3][B] | g_sound.u_note_manager/n26787_s6/F
21.147 | 3.264 | tNET | RR | 1 | R25C89[2][A] | g_sound.u_note_manager/same_idx_r_4_s0/CE

Data Required Path:

AT | DELAY | TYPE | RF | FANOUT | LOC | NODE
17.800 | 17.800 | | | | | active clock edge time
17.800 | 0.000 | | | | | clk_sys
17.800 | 0.000 | tCL | RR | 1 | IOB117[B] | clk_ibuf/I
19.088 | 1.288 | tINS | RR | 17271 | IOB117[B] | clk_ibuf/O
21.942 | 2.854 | tNET | RR | 1 | R25C89[2][A] | g_sound.u_note_manager/same_idx_r_4_s0/CLK
21.662 | -0.280 | tSu | | 1 | R25C89[2][A] | g_sound.u_note_manager/same_idx_r_4_s0

Path Statistics:

Clock Skew | -0.008
Setup Relationship | 17.800
Logic Level | 9
Arrival Clock Path Delay | cell: 1.288, 31.042%; route: 2.862, 68.958%
Arrival Data Path Delay | cell: 2.908, 17.110%; route: 12.280, 72.247%; tC2Q: 1.809, 10.643%
Required Clock Path Delay | cell: 1.288, 31.105%; route: 2.854, 68.895%

### Path6

Path Summary:

Slack | 1.250
Data Arrival Time | 20.404
Data Required Time | 21.653
From | g_sound.u_note_manager/fifo_ax_fifo_ax_0_0_s
To | g_sound.u_note_manager/scan_cnt_1_s0
Launch Clk | clk_sys:[R]
Latch Clk | clk_sys:[R]

Data Arrival Path:

AT | DELAY | TYPE | RF | FANOUT | LOC | NODE
0.000 | 0.000 | | | | | active clock edge time
0.000 | 0.000 | | | | | clk_sys
0.000 | 0.000 | tCL | RR | 1 | IOB117[B] | clk_ibuf/I
1.288 | 1.288 | tINS | RR | 17271 | IOB117[B] | clk_ibuf/O
4.150 | 2.862 | tNET | RR | 16 | BSRAM_R56[11][A] | g_sound.u_note_manager/fifo_ax_fifo_ax_0_0_s/CLKB
5.959 | 1.809 | tC2Q | RR | 35 | BSRAM_R56[11][A] | g_sound.u_note_manager/fifo_ax_fifo_ax_0_0_s/DO[2]
8.563 | 2.604 | tNET | RR | 2 | R71C55[1][A] | g_sound.u_note_manager/n1777_s0/I1
9.069 | 0.506 | tINS | RF | 1 | R71C55[1][A] | g_sound.u_note_manager/n1777_s0/COUT
9.069 | 0.000 | tNET | FF | 2 | R71C55[1][B] | g_sound.u_note_manager/n1778_s0/CIN
9.114 | 0.045 | tINS | FR | 2 | R71C55[1][B] | g_sound.u_note_manager/n1778_s0/COUT
11.406 | 2.292 | tNET | RR | 1 | R37C70[3][B] | g_sound.u_note_manager/same_valid_s24/I3
11.875 | 0.469 | tINS | RR | 3 | R37C70[3][B] | g_sound.u_note_manager/same_valid_s24/F
13.024 | 1.149 | tNET | RR | 1 | R25C89[2][B] | g_sound.u_note_manager/same_valid_s11/I1
13.439 | 0.415 | tINS | RR | 3 | R25C89[2][B] | g_sound.u_note_manager/same_valid_s11/F
13.756 | 0.317 | tNET | RR | 1 | R24C90[2][A] | g_sound.u_note_manager/same_valid_s4/I0
14.221 | 0.465 | tINS | RR | 2 | R24C90[2][A] | g_sound.u_note_manager/same_valid_s4/F
14.365 | 0.144 | tNET | RR | 1 | R25C90[3][B] | g_sound.u_note_manager/same_valid_s0/I3
14.738 | 0.373 | tINS | RR | 4 | R25C90[3][B] | g_sound.u_note_manager/same_valid_s0/F
17.560 | 2.822 | tNET | RR | 1 | R61C56[0][B] | g_sound.u_note_manager/n24370_s10/I2
18.024 | 0.465 | tINS | RR | 4 | R61C56[0][B] | g_sound.u_note_manager/n24370_s10/F
18.891 | 0.866 | tNET | RR | 1 | R61C51[2][A] | g_sound.u_note_manager/n26753_s12/I1
19.102 | 0.211 | tINS | RF | 34 | R61C51[2][A] | g_sound.u_note_manager/n26753_s12/F
19.850 | 0.748 | tNET | FF | 1 | R59C53[2][B] | g_sound.u_note_manager/scan_cnt_4_s6/I1
20.087 | 0.236 | tINS | FR | 4 | R59C53[2][B] | g_sound.u_note_manager/scan_cnt_4_s6/F
20.404 | 0.317 | tNET | RR | 1 | R58C53[0][A] | g_sound.u_note_manager/scan_cnt_1_s0/CE

Data Required Path:

AT | DELAY | TYPE | RF | FANOUT | LOC | NODE
17.800 | 17.800 | | | | | active clock edge time
17.800 | 0.000 | | | | | clk_sys
17.800 | 0.000 | tCL | RR | 1 | IOB117[B] | clk_ibuf/I
19.088 | 1.288 | tINS | RR | 17271 | IOB117[B] | clk_ibuf/O
21.933 | 2.845 | tNET | RR | 1 | R58C53[0][A] | g_sound.u_note_manager/scan_cnt_1_s0/CLK
21.653 | -0.280 | tSu | | 1 | R58C53[0][A] | g_sound.u_note_manager/scan_cnt_1_s0

Path Statistics:

Clock Skew | -0.017
Setup Relationship | 17.800
Logic Level | 10
Arrival Clock Path Delay | cell: 1.288, 31.042%; route: 2.862, 68.958%
Arrival Data Path Delay | cell: 3.186, 19.602%; route: 11.258, 69.268%; tC2Q: 1.809, 11.130%
Required Clock Path Delay | cell: 1.288, 31.169%; route: 2.845, 68.831%

### Path7

Path Summary:

Slack | 1.258
Data Arrival Time | 20.404
Data Required Time | 21.662
From | g_sound.u_note_manager/fifo_ax_fifo_ax_0_0_s
To | g_sound.u_note_manager/scan_cnt_3_s0
Launch Clk | clk_sys:[R]
Latch Clk | clk_sys:[R]

Data Arrival Path:

AT | DELAY | TYPE | RF | FANOUT | LOC | NODE
0.000 | 0.000 | | | | | active clock edge time
0.000 | 0.000 | | | | | clk_sys
0.000 | 0.000 | tCL | RR | 1 | IOB117[B] | clk_ibuf/I
1.288 | 1.288 | tINS | RR | 17271 | IOB117[B] | clk_ibuf/O
4.150 | 2.862 | tNET | RR | 16 | BSRAM_R56[11][A] | g_sound.u_note_manager/fifo_ax_fifo_ax_0_0_s/CLKB
5.959 | 1.809 | tC2Q | RR | 35 | BSRAM_R56[11][A] | g_sound.u_note_manager/fifo_ax_fifo_ax_0_0_s/DO[2]
8.563 | 2.604 | tNET | RR | 2 | R71C55[1][A] | g_sound.u_note_manager/n1777_s0/I1
9.069 | 0.506 | tINS | RF | 1 | R71C55[1][A] | g_sound.u_note_manager/n1777_s0/COUT
9.069 | 0.000 | tNET | FF | 2 | R71C55[1][B] | g_sound.u_note_manager/n1778_s0/CIN
9.114 | 0.045 | tINS | FR | 2 | R71C55[1][B] | g_sound.u_note_manager/n1778_s0/COUT
11.406 | 2.292 | tNET | RR | 1 | R37C70[3][B] | g_sound.u_note_manager/same_valid_s24/I3
11.875 | 0.469 | tINS | RR | 3 | R37C70[3][B] | g_sound.u_note_manager/same_valid_s24/F
13.024 | 1.149 | tNET | RR | 1 | R25C89[2][B] | g_sound.u_note_manager/same_valid_s11/I1
13.439 | 0.415 | tINS | RR | 3 | R25C89[2][B] | g_sound.u_note_manager/same_valid_s11/F
13.756 | 0.317 | tNET | RR | 1 | R24C90[2][A] | g_sound.u_note_manager/same_valid_s4/I0
14.221 | 0.465 | tINS | RR | 2 | R24C90[2][A] | g_sound.u_note_manager/same_valid_s4/F
14.365 | 0.144 | tNET | RR | 1 | R25C90[3][B] | g_sound.u_note_manager/same_valid_s0/I3
14.738 | 0.373 | tINS | RR | 4 | R25C90[3][B] | g_sound.u_note_manager/same_valid_s0/F
17.560 | 2.822 | tNET | RR | 1 | R61C56[0][B] | g_sound.u_note_manager/n24370_s10/I2
18.024 | 0.465 | tINS | RR | 4 | R61C56[0][B] | g_sound.u_note_manager/n24370_s10/F
18.891 | 0.866 | tNET | RR | 1 | R61C51[2][A] | g_sound.u_note_manager/n26753_s12/I1
19.102 | 0.211 | tINS | RF | 34 | R61C51[2][A] | g_sound.u_note_manager/n26753_s12/F
19.850 | 0.748 | tNET | FF | 1 | R59C53[2][B] | g_sound.u_note_manager/scan_cnt_4_s6/I1
20.087 | 0.236 | tINS | FR | 4 | R59C53[2][B] | g_sound.u_note_manager/scan_cnt_4_s6/F
20.404 | 0.317 | tNET | RR | 1 | R59C54[3][A] | g_sound.u_note_manager/scan_cnt_3_s0/CE

Data Required Path:

AT | DELAY | TYPE | RF | FANOUT | LOC | NODE
17.800 | 17.800 | | | | | active clock edge time
17.800 | 0.000 | | | | | clk_sys
17.800 | 0.000 | tCL | RR | 1 | IOB117[B] | clk_ibuf/I
19.088 | 1.288 | tINS | RR | 17271 | IOB117[B] | clk_ibuf/O
21.942 | 2.854 | tNET | RR | 1 | R59C54[3][A] | g_sound.u_note_manager/scan_cnt_3_s0/CLK
21.662 | -0.280 | tSu | | 1 | R59C54[3][A] | g_sound.u_note_manager/scan_cnt_3_s0

Path Statistics:

Clock Skew | -0.008
Setup Relationship | 17.800
Logic Level | 10
Arrival Clock Path Delay | cell: 1.288, 31.042%; route: 2.862, 68.958%
Arrival Data Path Delay | cell: 3.186, 19.602%; route: 11.258, 69.268%; tC2Q: 1.809, 11.130%
Required Clock Path Delay | cell: 1.288, 31.105%; route: 2.854, 68.895%

### Path8

Path Summary:

Slack | 1.378
Data Arrival Time | 20.506
Data Required Time | 21.885
From | g_sound.u_envelope_bank/dec_r_0_s0
To | g_sound.u_envelope_bank/env_level_o_57_s0
Launch Clk | clk_sys:[R]
Latch Clk | clk_sys:[R]

Data Arrival Path:

AT | DELAY | TYPE | RF | FANOUT | LOC | NODE
0.000 | 0.000 | | | | | active clock edge time
0.000 | 0.000 | | | | | clk_sys
0.000 | 0.000 | tCL | RR | 1 | IOB117[B] | clk_ibuf/I
1.288 | 1.288 | tINS | RR | 17271 | IOB117[B] | clk_ibuf/O
4.142 | 2.854 | tNET | RR | 1 | R13C95[1][A] | g_sound.u_envelope_bank/dec_r_0_s0/CLK
4.486 | 0.344 | tC2Q | RR | 2 | R13C95[1][A] | g_sound.u_envelope_bank/dec_r_0_s0/Q
5.811 | 1.325 | tNET | RR | 2 | R16C76[0][A] | g_sound.u_envelope_bank/n1798_s/I1
6.255 | 0.443 | tINS | RR | 1 | R16C76[0][A] | g_sound.u_envelope_bank/n1798_s/COUT
6.255 | 0.000 | tNET | RR | 2 | R16C76[0][B] | g_sound.u_envelope_bank/n1797_s/CIN
6.526 | 0.271 | tINS | RF | 1 | R16C76[0][B] | g_sound.u_envelope_bank/n1797_s/SUM
6.530 | 0.005 | tNET | FF | 1 | R16C76[3][A] | g_sound.u_envelope_bank/lvl_n_0_s36/I0
6.999 | 0.469 | tINS | FR | 1 | R16C76[3][A] | g_sound.u_envelope_bank/lvl_n_0_s36/F
7.141 | 0.142 | tNET | RR | 1 | R17C76[0][B] | g_sound.u_envelope_bank/lvl_n_0_s35/I2
7.606 | 0.465 | tINS | RR | 1 | R17C76[0][B] | g_sound.u_envelope_bank/lvl_n_0_s35/F
7.748 | 0.142 | tNET | RR | 1 | R16C76[3][B] | g_sound.u_envelope_bank/lvl_n_0_s34/I0
8.121 | 0.373 | tINS | RR | 1 | R16C76[3][B] | g_sound.u_envelope_bank/lvl_n_0_s34/F
8.294 | 0.173 | tNET | RR | 1 | R15C76[1][B] | g_sound.u_envelope_bank/lvl_n_0_s38/I3
8.768 | 0.474 | tINS | RR | 1 | R15C76[1][B] | g_sound.u_envelope_bank/lvl_n_0_s38/F
8.770 | 0.002 | tNET | RR | 1 | R15C76[0][B] | g_sound.u_envelope_bank/lvl_n_0_s23/I0
9.235 | 0.465 | tINS | RR | 1 | R15C76[0][B] | g_sound.u_envelope_bank/lvl_n_0_s23/F
9.548 | 0.313 | tNET | RR | 1 | R13C77[3][A] | g_sound.u_envelope_bank/lvl_n_0_s18/I0
9.786 | 0.238 | tINS | RR | 1 | R13C77[3][A] | g_sound.u_envelope_bank/lvl_n_0_s18/F
10.270 | 0.484 | tNET | RR | 1 | R9C77[1][B] | g_sound.u_envelope_bank/lvl_n_0_s15/I0
10.685 | 0.415 | tINS | RR | 10 | R9C77[1][B] | g_sound.u_envelope_bank/lvl_n_0_s15/F
11.724 | 1.039 | tNET | RR | 1 | R4C78[2][B] | g_sound.u_envelope_bank/st_n_0_s4/I1
12.140 | 0.415 | tINS | RR | 19 | R4C78[2][B] | g_sound.u_envelope_bank/st_n_0_s4/F
12.466 | 0.326 | tNET | RR | 1 | R6C77[0][A] | g_sound.u_envelope_bank/lvl_n_9_s7/I2
12.881 | 0.415 | tINS | RR | 2 | R6C77[0][A] | g_sound.u_envelope_bank/lvl_n_9_s7/F
13.196 | 0.315 | tNET | RR | 1 | R3C77[1][B] | g_sound.u_envelope_bank/lvl_n_9_s6/I3
13.611 | 0.415 | tINS | RR | 1 | R3C77[1][B] | g_sound.u_envelope_bank/lvl_n_9_s6/F
13.613 | 0.002 | tNET | RR | 1 | R3C77[0][A] | g_sound.u_envelope_bank/lvl_n_9_s3/I1
14.078 | 0.465 | tINS | RR | 1 | R3C77[0][A] | g_sound.u_envelope_bank/lvl_n_9_s3/F
14.080 | 0.002 | tNET | RR | 1 | R3C77[2][B] | g_sound.u_envelope_bank/lvl_n_9_s2/I0
14.316 | 0.236 | tINS | RR | 33 | R3C77[2][B] | g_sound.u_envelope_bank/lvl_n_9_s2/F
20.506 | 6.190 | tNET | RR | 1 | R52C87[0][A] | g_sound.u_envelope_bank/env_level_o_57_s0/D

Data Required Path:

AT | DELAY | TYPE | RF | FANOUT | LOC | NODE
17.800 | 17.800 | | | | | active clock edge time
17.800 | 0.000 | | | | | clk_sys
17.800 | 0.000 | tCL | RR | 1 | IOB117[B] | clk_ibuf/I
19.088 | 1.288 | tINS | RR | 17271 | IOB117[B] | clk_ibuf/O
21.942 | 2.854 | tNET | RR | 1 | R52C87[0][A] | g_sound.u_envelope_bank/env_level_o_57_s0/CLK
21.885 | -0.057 | tSu | | 1 | R52C87[0][A] | g_sound.u_envelope_bank/env_level_o_57_s0

Path Statistics:

Clock Skew | 0.000
Setup Relationship | 17.800
Logic Level | 15
Arrival Clock Path Delay | cell: 1.288, 31.105%; route: 2.854, 68.895%
Arrival Data Path Delay | cell: 5.560, 33.975%; route: 10.460, 63.921%; tC2Q: 0.344, 2.104%
Required Clock Path Delay | cell: 1.288, 31.105%; route: 2.854, 68.895%

### Path9

Path Summary:

Slack | 1.436
Data Arrival Time | 20.217
Data Required Time | 21.653
From | g_sound.u_note_manager/fifo_ax_fifo_ax_0_0_s
To | g_sound.u_note_manager/scan_cnt_2_s0
Launch Clk | clk_sys:[R]
Latch Clk | clk_sys:[R]

Data Arrival Path:

AT | DELAY | TYPE | RF | FANOUT | LOC | NODE
0.000 | 0.000 | | | | | active clock edge time
0.000 | 0.000 | | | | | clk_sys
0.000 | 0.000 | tCL | RR | 1 | IOB117[B] | clk_ibuf/I
1.288 | 1.288 | tINS | RR | 17271 | IOB117[B] | clk_ibuf/O
4.150 | 2.862 | tNET | RR | 16 | BSRAM_R56[11][A] | g_sound.u_note_manager/fifo_ax_fifo_ax_0_0_s/CLKB
5.959 | 1.809 | tC2Q | RR | 35 | BSRAM_R56[11][A] | g_sound.u_note_manager/fifo_ax_fifo_ax_0_0_s/DO[2]
8.563 | 2.604 | tNET | RR | 2 | R71C55[1][A] | g_sound.u_note_manager/n1777_s0/I1
9.069 | 0.506 | tINS | RF | 1 | R71C55[1][A] | g_sound.u_note_manager/n1777_s0/COUT
9.069 | 0.000 | tNET | FF | 2 | R71C55[1][B] | g_sound.u_note_manager/n1778_s0/CIN
9.114 | 0.045 | tINS | FR | 2 | R71C55[1][B] | g_sound.u_note_manager/n1778_s0/COUT
11.406 | 2.292 | tNET | RR | 1 | R37C70[3][B] | g_sound.u_note_manager/same_valid_s24/I3
11.875 | 0.469 | tINS | RR | 3 | R37C70[3][B] | g_sound.u_note_manager/same_valid_s24/F
13.024 | 1.149 | tNET | RR | 1 | R25C89[2][B] | g_sound.u_note_manager/same_valid_s11/I1
13.439 | 0.415 | tINS | RR | 3 | R25C89[2][B] | g_sound.u_note_manager/same_valid_s11/F
13.756 | 0.317 | tNET | RR | 1 | R24C90[2][A] | g_sound.u_note_manager/same_valid_s4/I0
14.221 | 0.465 | tINS | RR | 2 | R24C90[2][A] | g_sound.u_note_manager/same_valid_s4/F
14.365 | 0.144 | tNET | RR | 1 | R25C90[3][B] | g_sound.u_note_manager/same_valid_s0/I3
14.738 | 0.373 | tINS | RR | 4 | R25C90[3][B] | g_sound.u_note_manager/same_valid_s0/F
17.560 | 2.822 | tNET | RR | 1 | R61C56[0][B] | g_sound.u_note_manager/n24370_s10/I2
18.024 | 0.465 | tINS | RR | 4 | R61C56[0][B] | g_sound.u_note_manager/n24370_s10/F
18.891 | 0.866 | tNET | RR | 1 | R61C51[2][A] | g_sound.u_note_manager/n26753_s12/I1
19.102 | 0.211 | tINS | RF | 34 | R61C51[2][A] | g_sound.u_note_manager/n26753_s12/F
19.850 | 0.748 | tNET | FF | 1 | R59C53[2][B] | g_sound.u_note_manager/scan_cnt_4_s6/I1
20.087 | 0.236 | tINS | FR | 4 | R59C53[2][B] | g_sound.u_note_manager/scan_cnt_4_s6/F
20.217 | 0.130 | tNET | RR | 1 | R59C53[0][A] | g_sound.u_note_manager/scan_cnt_2_s0/CE

Data Required Path:

AT | DELAY | TYPE | RF | FANOUT | LOC | NODE
17.800 | 17.800 | | | | | active clock edge time
17.800 | 0.000 | | | | | clk_sys
17.800 | 0.000 | tCL | RR | 1 | IOB117[B] | clk_ibuf/I
19.088 | 1.288 | tINS | RR | 17271 | IOB117[B] | clk_ibuf/O
21.933 | 2.845 | tNET | RR | 1 | R59C53[0][A] | g_sound.u_note_manager/scan_cnt_2_s0/CLK
21.653 | -0.280 | tSu | | 1 | R59C53[0][A] | g_sound.u_note_manager/scan_cnt_2_s0

Path Statistics:

Clock Skew | -0.017
Setup Relationship | 17.800
Logic Level | 10
Arrival Clock Path Delay | cell: 1.288, 31.042%; route: 2.862, 68.958%
Arrival Data Path Delay | cell: 3.186, 19.830%; route: 11.072, 68.911%; tC2Q: 1.809, 11.259%
Required Clock Path Delay | cell: 1.288, 31.169%; route: 2.845, 68.831%

### Path10

Path Summary:

Slack | 1.436
Data Arrival Time | 20.217
Data Required Time | 21.653
From | g_sound.u_note_manager/fifo_ax_fifo_ax_0_0_s
To | g_sound.u_note_manager/scan_cnt_4_s0
Launch Clk | clk_sys:[R]
Latch Clk | clk_sys:[R]

Data Arrival Path:

AT | DELAY | TYPE | RF | FANOUT | LOC | NODE
0.000 | 0.000 | | | | | active clock edge time
0.000 | 0.000 | | | | | clk_sys
0.000 | 0.000 | tCL | RR | 1 | IOB117[B] | clk_ibuf/I
1.288 | 1.288 | tINS | RR | 17271 | IOB117[B] | clk_ibuf/O
4.150 | 2.862 | tNET | RR | 16 | BSRAM_R56[11][A] | g_sound.u_note_manager/fifo_ax_fifo_ax_0_0_s/CLKB
5.959 | 1.809 | tC2Q | RR | 35 | BSRAM_R56[11][A] | g_sound.u_note_manager/fifo_ax_fifo_ax_0_0_s/DO[2]
8.563 | 2.604 | tNET | RR | 2 | R71C55[1][A] | g_sound.u_note_manager/n1777_s0/I1
9.069 | 0.506 | tINS | RF | 1 | R71C55[1][A] | g_sound.u_note_manager/n1777_s0/COUT
9.069 | 0.000 | tNET | FF | 2 | R71C55[1][B] | g_sound.u_note_manager/n1778_s0/CIN
9.114 | 0.045 | tINS | FR | 2 | R71C55[1][B] | g_sound.u_note_manager/n1778_s0/COUT
11.406 | 2.292 | tNET | RR | 1 | R37C70[3][B] | g_sound.u_note_manager/same_valid_s24/I3
11.875 | 0.469 | tINS | RR | 3 | R37C70[3][B] | g_sound.u_note_manager/same_valid_s24/F
13.024 | 1.149 | tNET | RR | 1 | R25C89[2][B] | g_sound.u_note_manager/same_valid_s11/I1
13.439 | 0.415 | tINS | RR | 3 | R25C89[2][B] | g_sound.u_note_manager/same_valid_s11/F
13.756 | 0.317 | tNET | RR | 1 | R24C90[2][A] | g_sound.u_note_manager/same_valid_s4/I0
14.221 | 0.465 | tINS | RR | 2 | R24C90[2][A] | g_sound.u_note_manager/same_valid_s4/F
14.365 | 0.144 | tNET | RR | 1 | R25C90[3][B] | g_sound.u_note_manager/same_valid_s0/I3
14.738 | 0.373 | tINS | RR | 4 | R25C90[3][B] | g_sound.u_note_manager/same_valid_s0/F
17.560 | 2.822 | tNET | RR | 1 | R61C56[0][B] | g_sound.u_note_manager/n24370_s10/I2
18.024 | 0.465 | tINS | RR | 4 | R61C56[0][B] | g_sound.u_note_manager/n24370_s10/F
18.891 | 0.866 | tNET | RR | 1 | R61C51[2][A] | g_sound.u_note_manager/n26753_s12/I1
19.102 | 0.211 | tINS | RF | 34 | R61C51[2][A] | g_sound.u_note_manager/n26753_s12/F
19.850 | 0.748 | tNET | FF | 1 | R59C53[2][B] | g_sound.u_note_manager/scan_cnt_4_s6/I1
20.087 | 0.236 | tINS | FR | 4 | R59C53[2][B] | g_sound.u_note_manager/scan_cnt_4_s6/F
20.217 | 0.130 | tNET | RR | 1 | R59C53[1][B] | g_sound.u_note_manager/scan_cnt_4_s0/CE

Data Required Path:

AT | DELAY | TYPE | RF | FANOUT | LOC | NODE
17.800 | 17.800 | | | | | active clock edge time
17.800 | 0.000 | | | | | clk_sys
17.800 | 0.000 | tCL | RR | 1 | IOB117[B] | clk_ibuf/I
19.088 | 1.288 | tINS | RR | 17271 | IOB117[B] | clk_ibuf/O
21.933 | 2.845 | tNET | RR | 1 | R59C53[1][B] | g_sound.u_note_manager/scan_cnt_4_s0/CLK
21.653 | -0.280 | tSu | | 1 | R59C53[1][B] | g_sound.u_note_manager/scan_cnt_4_s0

Path Statistics:

Clock Skew | -0.017
Setup Relationship | 17.800
Logic Level | 10
Arrival Clock Path Delay | cell: 1.288, 31.042%; route: 2.862, 68.958%
Arrival Data Path Delay | cell: 3.186, 19.830%; route: 11.072, 68.911%; tC2Q: 1.809, 11.259%
Required Clock Path Delay | cell: 1.288, 31.169%; route: 2.845, 68.831%

### Path11

Path Summary:

Slack | 1.708
Data Arrival Time | 20.177
Data Required Time | 21.885
From | g_sound.u_note_manager/fifo_ax_fifo_ax_0_0_s
To | g_sound.u_note_manager/vtgt_vld_vtgt_vld_RAMREG_13_G[0]_s0
Launch Clk | clk_sys:[R]
Latch Clk | clk_sys:[R]

Data Arrival Path:

AT | DELAY | TYPE | RF | FANOUT | LOC | NODE
0.000 | 0.000 | | | | | active clock edge time
0.000 | 0.000 | | | | | clk_sys
0.000 | 0.000 | tCL | RR | 1 | IOB117[B] | clk_ibuf/I
1.288 | 1.288 | tINS | RR | 17271 | IOB117[B] | clk_ibuf/O
4.150 | 2.862 | tNET | RR | 16 | BSRAM_R56[11][A] | g_sound.u_note_manager/fifo_ax_fifo_ax_0_0_s/CLKB
5.959 | 1.809 | tC2Q | RR | 35 | BSRAM_R56[11][A] | g_sound.u_note_manager/fifo_ax_fifo_ax_0_0_s/DO[2]
8.563 | 2.604 | tNET | RR | 2 | R71C55[1][A] | g_sound.u_note_manager/n1777_s0/I1
9.069 | 0.506 | tINS | RF | 1 | R71C55[1][A] | g_sound.u_note_manager/n1777_s0/COUT
9.069 | 0.000 | tNET | FF | 2 | R71C55[1][B] | g_sound.u_note_manager/n1778_s0/CIN
9.114 | 0.045 | tINS | FR | 2 | R71C55[1][B] | g_sound.u_note_manager/n1778_s0/COUT
11.406 | 2.292 | tNET | RR | 1 | R37C70[3][B] | g_sound.u_note_manager/same_valid_s24/I3
11.875 | 0.469 | tINS | RR | 3 | R37C70[3][B] | g_sound.u_note_manager/same_valid_s24/F
13.024 | 1.149 | tNET | RR | 1 | R25C89[2][B] | g_sound.u_note_manager/same_valid_s11/I1
13.439 | 0.415 | tINS | RR | 3 | R25C89[2][B] | g_sound.u_note_manager/same_valid_s11/F
13.756 | 0.317 | tNET | RR | 1 | R24C90[2][A] | g_sound.u_note_manager/same_valid_s4/I0
14.221 | 0.465 | tINS | RR | 2 | R24C90[2][A] | g_sound.u_note_manager/same_valid_s4/F
14.365 | 0.144 | tNET | RR | 1 | R25C90[3][B] | g_sound.u_note_manager/same_valid_s0/I3
14.738 | 0.373 | tINS | RR | 4 | R25C90[3][B] | g_sound.u_note_manager/same_valid_s0/F
17.560 | 2.822 | tNET | RR | 1 | R61C56[0][B] | g_sound.u_note_manager/n24370_s10/I2
18.024 | 0.465 | tINS | RR | 4 | R61C56[0][B] | g_sound.u_note_manager/n24370_s10/F
18.168 | 0.144 | tNET | RR | 1 | R62C56[0][A] | g_sound.u_note_manager/vtgt_vld_s371/I1
18.380 | 0.211 | tINS | RF | 16 | R62C56[0][A] | g_sound.u_note_manager/vtgt_vld_s371/F
19.761 | 1.382 | tNET | FF | 1 | R63C68[2][A] | g_sound.u_note_manager/vtgt_vld_s361/I0
20.177 | 0.415 | tINS | FR | 1 | R63C68[2][A] | g_sound.u_note_manager/vtgt_vld_s361/F
20.177 | 0.000 | tNET | RR | 1 | R63C68[2][A] | g_sound.u_note_manager/vtgt_vld_vtgt_vld_RAMREG_13_G[0]_s0/D

Data Required Path:

AT | DELAY | TYPE | RF | FANOUT | LOC | NODE
17.800 | 17.800 | | | | | active clock edge time
17.800 | 0.000 | | | | | clk_sys
17.800 | 0.000 | tCL | RR | 1 | IOB117[B] | clk_ibuf/I
19.088 | 1.288 | tINS | RR | 17271 | IOB117[B] | clk_ibuf/O
21.942 | 2.854 | tNET | RR | 1 | R63C68[2][A] | g_sound.u_note_manager/vtgt_vld_vtgt_vld_RAMREG_13_G[0]_s0/CLK
21.885 | -0.057 | tSu | | 1 | R63C68[2][A] | g_sound.u_note_manager/vtgt_vld_vtgt_vld_RAMREG_13_G[0]_s0

Path Statistics:

Clock Skew | -0.008
Setup Relationship | 17.800
Logic Level | 10
Arrival Clock Path Delay | cell: 1.288, 31.042%; route: 2.862, 68.958%
Arrival Data Path Delay | cell: 3.365, 20.996%; route: 10.852, 67.716%; tC2Q: 1.809, 11.288%
Required Clock Path Delay | cell: 1.288, 31.105%; route: 2.854, 68.895%

### Path12

Path Summary:

Slack | 1.712
Data Arrival Time | 20.164
Data Required Time | 21.876
From | g_sound.u_envelope_bank/dec_r_0_s0
To | g_sound.u_envelope_bank/env_level_o_9_s0
Launch Clk | clk_sys:[R]
Latch Clk | clk_sys:[R]

Data Arrival Path:

AT | DELAY | TYPE | RF | FANOUT | LOC | NODE
0.000 | 0.000 | | | | | active clock edge time
0.000 | 0.000 | | | | | clk_sys
0.000 | 0.000 | tCL | RR | 1 | IOB117[B] | clk_ibuf/I
1.288 | 1.288 | tINS | RR | 17271 | IOB117[B] | clk_ibuf/O
4.142 | 2.854 | tNET | RR | 1 | R13C95[1][A] | g_sound.u_envelope_bank/dec_r_0_s0/CLK
4.486 | 0.344 | tC2Q | RR | 2 | R13C95[1][A] | g_sound.u_envelope_bank/dec_r_0_s0/Q
5.811 | 1.325 | tNET | RR | 2 | R16C76[0][A] | g_sound.u_envelope_bank/n1798_s/I1
6.255 | 0.443 | tINS | RR | 1 | R16C76[0][A] | g_sound.u_envelope_bank/n1798_s/COUT
6.255 | 0.000 | tNET | RR | 2 | R16C76[0][B] | g_sound.u_envelope_bank/n1797_s/CIN
6.526 | 0.271 | tINS | RF | 1 | R16C76[0][B] | g_sound.u_envelope_bank/n1797_s/SUM
6.530 | 0.005 | tNET | FF | 1 | R16C76[3][A] | g_sound.u_envelope_bank/lvl_n_0_s36/I0
6.999 | 0.469 | tINS | FR | 1 | R16C76[3][A] | g_sound.u_envelope_bank/lvl_n_0_s36/F
7.141 | 0.142 | tNET | RR | 1 | R17C76[0][B] | g_sound.u_envelope_bank/lvl_n_0_s35/I2
7.606 | 0.465 | tINS | RR | 1 | R17C76[0][B] | g_sound.u_envelope_bank/lvl_n_0_s35/F
7.748 | 0.142 | tNET | RR | 1 | R16C76[3][B] | g_sound.u_envelope_bank/lvl_n_0_s34/I0
8.121 | 0.373 | tINS | RR | 1 | R16C76[3][B] | g_sound.u_envelope_bank/lvl_n_0_s34/F
8.294 | 0.173 | tNET | RR | 1 | R15C76[1][B] | g_sound.u_envelope_bank/lvl_n_0_s38/I3
8.768 | 0.474 | tINS | RR | 1 | R15C76[1][B] | g_sound.u_envelope_bank/lvl_n_0_s38/F
8.770 | 0.002 | tNET | RR | 1 | R15C76[0][B] | g_sound.u_envelope_bank/lvl_n_0_s23/I0
9.235 | 0.465 | tINS | RR | 1 | R15C76[0][B] | g_sound.u_envelope_bank/lvl_n_0_s23/F
9.548 | 0.313 | tNET | RR | 1 | R13C77[3][A] | g_sound.u_envelope_bank/lvl_n_0_s18/I0
9.786 | 0.238 | tINS | RR | 1 | R13C77[3][A] | g_sound.u_envelope_bank/lvl_n_0_s18/F
10.270 | 0.484 | tNET | RR | 1 | R9C77[1][B] | g_sound.u_envelope_bank/lvl_n_0_s15/I0
10.685 | 0.415 | tINS | RR | 10 | R9C77[1][B] | g_sound.u_envelope_bank/lvl_n_0_s15/F
11.724 | 1.039 | tNET | RR | 1 | R4C78[2][B] | g_sound.u_envelope_bank/st_n_0_s4/I1
12.140 | 0.415 | tINS | RR | 19 | R4C78[2][B] | g_sound.u_envelope_bank/st_n_0_s4/F
12.466 | 0.326 | tNET | RR | 1 | R6C77[0][A] | g_sound.u_envelope_bank/lvl_n_9_s7/I2
12.881 | 0.415 | tINS | RR | 2 | R6C77[0][A] | g_sound.u_envelope_bank/lvl_n_9_s7/F
13.196 | 0.315 | tNET | RR | 1 | R3C77[1][B] | g_sound.u_envelope_bank/lvl_n_9_s6/I3
13.611 | 0.415 | tINS | RR | 1 | R3C77[1][B] | g_sound.u_envelope_bank/lvl_n_9_s6/F
13.613 | 0.002 | tNET | RR | 1 | R3C77[0][A] | g_sound.u_envelope_bank/lvl_n_9_s3/I1
14.078 | 0.465 | tINS | RR | 1 | R3C77[0][A] | g_sound.u_envelope_bank/lvl_n_9_s3/F
14.080 | 0.002 | tNET | RR | 1 | R3C77[2][B] | g_sound.u_envelope_bank/lvl_n_9_s2/I0
14.316 | 0.236 | tINS | RR | 33 | R3C77[2][B] | g_sound.u_envelope_bank/lvl_n_9_s2/F
20.164 | 5.848 | tNET | RR | 1 | R52C86[1][A] | g_sound.u_envelope_bank/env_level_o_9_s0/D

Data Required Path:

AT | DELAY | TYPE | RF | FANOUT | LOC | NODE
17.800 | 17.800 | | | | | active clock edge time
17.800 | 0.000 | | | | | clk_sys
17.800 | 0.000 | tCL | RR | 1 | IOB117[B] | clk_ibuf/I
19.088 | 1.288 | tINS | RR | 17271 | IOB117[B] | clk_ibuf/O
21.933 | 2.845 | tNET | RR | 1 | R52C86[1][A] | g_sound.u_envelope_bank/env_level_o_9_s0/CLK
21.876 | -0.057 | tSu | | 1 | R52C86[1][A] | g_sound.u_envelope_bank/env_level_o_9_s0

Path Statistics:

Clock Skew | -0.008
Setup Relationship | 17.800
Logic Level | 15
Arrival Clock Path Delay | cell: 1.288, 31.105%; route: 2.854, 68.895%
Arrival Data Path Delay | cell: 5.560, 34.700%; route: 10.118, 63.151%; tC2Q: 0.344, 2.149%
Required Clock Path Delay | cell: 1.288, 31.169%; route: 2.845, 68.831%

### Path13

Path Summary:

Slack | 1.713
Data Arrival Time | 20.163
Data Required Time | 21.876
From | g_sound.u_note_manager/fifo_ax_fifo_ax_0_0_s
To | g_sound.u_note_manager/vtgt_vld_vtgt_vld_RAMREG_14_G[0]_s0
Launch Clk | clk_sys:[R]
Latch Clk | clk_sys:[R]

Data Arrival Path:

AT | DELAY | TYPE | RF | FANOUT | LOC | NODE
0.000 | 0.000 | | | | | active clock edge time
0.000 | 0.000 | | | | | clk_sys
0.000 | 0.000 | tCL | RR | 1 | IOB117[B] | clk_ibuf/I
1.288 | 1.288 | tINS | RR | 17271 | IOB117[B] | clk_ibuf/O
4.150 | 2.862 | tNET | RR | 16 | BSRAM_R56[11][A] | g_sound.u_note_manager/fifo_ax_fifo_ax_0_0_s/CLKB
5.959 | 1.809 | tC2Q | RR | 35 | BSRAM_R56[11][A] | g_sound.u_note_manager/fifo_ax_fifo_ax_0_0_s/DO[2]
8.563 | 2.604 | tNET | RR | 2 | R71C55[1][A] | g_sound.u_note_manager/n1777_s0/I1
9.069 | 0.506 | tINS | RF | 1 | R71C55[1][A] | g_sound.u_note_manager/n1777_s0/COUT
9.069 | 0.000 | tNET | FF | 2 | R71C55[1][B] | g_sound.u_note_manager/n1778_s0/CIN
9.114 | 0.045 | tINS | FR | 2 | R71C55[1][B] | g_sound.u_note_manager/n1778_s0/COUT
11.406 | 2.292 | tNET | RR | 1 | R37C70[3][B] | g_sound.u_note_manager/same_valid_s24/I3
11.875 | 0.469 | tINS | RR | 3 | R37C70[3][B] | g_sound.u_note_manager/same_valid_s24/F
13.024 | 1.149 | tNET | RR | 1 | R25C89[2][B] | g_sound.u_note_manager/same_valid_s11/I1
13.439 | 0.415 | tINS | RR | 3 | R25C89[2][B] | g_sound.u_note_manager/same_valid_s11/F
13.756 | 0.317 | tNET | RR | 1 | R24C90[2][A] | g_sound.u_note_manager/same_valid_s4/I0
14.221 | 0.465 | tINS | RR | 2 | R24C90[2][A] | g_sound.u_note_manager/same_valid_s4/F
14.365 | 0.144 | tNET | RR | 1 | R25C90[3][B] | g_sound.u_note_manager/same_valid_s0/I3
14.738 | 0.373 | tINS | RR | 4 | R25C90[3][B] | g_sound.u_note_manager/same_valid_s0/F
17.560 | 2.822 | tNET | RR | 1 | R61C56[0][B] | g_sound.u_note_manager/n24370_s10/I2
18.024 | 0.465 | tINS | RR | 4 | R61C56[0][B] | g_sound.u_note_manager/n24370_s10/F
18.168 | 0.144 | tNET | RR | 1 | R62C56[0][A] | g_sound.u_note_manager/vtgt_vld_s371/I1
18.380 | 0.211 | tINS | RF | 16 | R62C56[0][A] | g_sound.u_note_manager/vtgt_vld_s371/F
19.927 | 1.547 | tNET | FF | 1 | R63C69[2][A] | g_sound.u_note_manager/vtgt_vld_s362/I0
20.163 | 0.236 | tINS | FR | 1 | R63C69[2][A] | g_sound.u_note_manager/vtgt_vld_s362/F
20.163 | 0.000 | tNET | RR | 1 | R63C69[2][A] | g_sound.u_note_manager/vtgt_vld_vtgt_vld_RAMREG_14_G[0]_s0/D

Data Required Path:

AT | DELAY | TYPE | RF | FANOUT | LOC | NODE
17.800 | 17.800 | | | | | active clock edge time
17.800 | 0.000 | | | | | clk_sys
17.800 | 0.000 | tCL | RR | 1 | IOB117[B] | clk_ibuf/I
19.088 | 1.288 | tINS | RR | 17271 | IOB117[B] | clk_ibuf/O
21.933 | 2.845 | tNET | RR | 1 | R63C69[2][A] | g_sound.u_note_manager/vtgt_vld_vtgt_vld_RAMREG_14_G[0]_s0/CLK
21.876 | -0.057 | tSu | | 1 | R63C69[2][A] | g_sound.u_note_manager/vtgt_vld_vtgt_vld_RAMREG_14_G[0]_s0

Path Statistics:

Clock Skew | -0.017
Setup Relationship | 17.800
Logic Level | 10
Arrival Clock Path Delay | cell: 1.288, 31.042%; route: 2.862, 68.958%
Arrival Data Path Delay | cell: 3.186, 19.897%; route: 11.018, 68.806%; tC2Q: 1.809, 11.297%
Required Clock Path Delay | cell: 1.288, 31.169%; route: 2.845, 68.831%

### Path14

Path Summary:

Slack | 1.776
Data Arrival Time | 20.100
Data Required Time | 21.876
From | g_sound.u_note_manager/fifo_ax_fifo_ax_0_0_s
To | g_sound.u_note_manager/scan_cnt_0_s3
Launch Clk | clk_sys:[R]
Latch Clk | clk_sys:[R]

Data Arrival Path:

AT | DELAY | TYPE | RF | FANOUT | LOC | NODE
0.000 | 0.000 | | | | | active clock edge time
0.000 | 0.000 | | | | | clk_sys
0.000 | 0.000 | tCL | RR | 1 | IOB117[B] | clk_ibuf/I
1.288 | 1.288 | tINS | RR | 17271 | IOB117[B] | clk_ibuf/O
4.150 | 2.862 | tNET | RR | 16 | BSRAM_R56[11][A] | g_sound.u_note_manager/fifo_ax_fifo_ax_0_0_s/CLKB
5.959 | 1.809 | tC2Q | RR | 35 | BSRAM_R56[11][A] | g_sound.u_note_manager/fifo_ax_fifo_ax_0_0_s/DO[2]
8.563 | 2.604 | tNET | RR | 2 | R71C55[1][A] | g_sound.u_note_manager/n1777_s0/I1
9.069 | 0.506 | tINS | RF | 1 | R71C55[1][A] | g_sound.u_note_manager/n1777_s0/COUT
9.069 | 0.000 | tNET | FF | 2 | R71C55[1][B] | g_sound.u_note_manager/n1778_s0/CIN
9.114 | 0.045 | tINS | FR | 2 | R71C55[1][B] | g_sound.u_note_manager/n1778_s0/COUT
11.406 | 2.292 | tNET | RR | 1 | R37C70[3][B] | g_sound.u_note_manager/same_valid_s24/I3
11.875 | 0.469 | tINS | RR | 3 | R37C70[3][B] | g_sound.u_note_manager/same_valid_s24/F
13.024 | 1.149 | tNET | RR | 1 | R25C89[2][B] | g_sound.u_note_manager/same_valid_s11/I1
13.439 | 0.415 | tINS | RR | 3 | R25C89[2][B] | g_sound.u_note_manager/same_valid_s11/F
13.756 | 0.317 | tNET | RR | 1 | R24C90[2][A] | g_sound.u_note_manager/same_valid_s4/I0
14.221 | 0.465 | tINS | RR | 2 | R24C90[2][A] | g_sound.u_note_manager/same_valid_s4/F
14.365 | 0.144 | tNET | RR | 1 | R25C90[3][B] | g_sound.u_note_manager/same_valid_s0/I3
14.738 | 0.373 | tINS | RR | 4 | R25C90[3][B] | g_sound.u_note_manager/same_valid_s0/F
17.560 | 2.822 | tNET | RR | 1 | R61C56[0][B] | g_sound.u_note_manager/n24370_s10/I2
18.024 | 0.465 | tINS | RR | 4 | R61C56[0][B] | g_sound.u_note_manager/n24370_s10/F
18.891 | 0.866 | tNET | RR | 1 | R61C51[2][A] | g_sound.u_note_manager/n26753_s12/I1
19.102 | 0.211 | tINS | RF | 34 | R61C51[2][A] | g_sound.u_note_manager/n26753_s12/F
19.685 | 0.583 | tNET | FF | 1 | R60C53[0][A] | g_sound.u_note_manager/n26752_s13/I2
20.100 | 0.415 | tINS | FR | 1 | R60C53[0][A] | g_sound.u_note_manager/n26752_s13/F
20.100 | 0.000 | tNET | RR | 1 | R60C53[0][A] | g_sound.u_note_manager/scan_cnt_0_s3/D

Data Required Path:

AT | DELAY | TYPE | RF | FANOUT | LOC | NODE
17.800 | 17.800 | | | | | active clock edge time
17.800 | 0.000 | | | | | clk_sys
17.800 | 0.000 | tCL | RR | 1 | IOB117[B] | clk_ibuf/I
19.088 | 1.288 | tINS | RR | 17271 | IOB117[B] | clk_ibuf/O
21.933 | 2.845 | tNET | RR | 1 | R60C53[0][A] | g_sound.u_note_manager/scan_cnt_0_s3/CLK
21.876 | -0.057 | tSu | | 1 | R60C53[0][A] | g_sound.u_note_manager/scan_cnt_0_s3

Path Statistics:

Clock Skew | -0.017
Setup Relationship | 17.800
Logic Level | 10
Arrival Clock Path Delay | cell: 1.288, 31.042%; route: 2.862, 68.958%
Arrival Data Path Delay | cell: 3.365, 21.097%; route: 10.776, 67.561%; tC2Q: 1.809, 11.342%
Required Clock Path Delay | cell: 1.288, 31.169%; route: 2.845, 68.831%

### Path15

Path Summary:

Slack | 1.801
Data Arrival Time | 20.083
Data Required Time | 21.885
From | g_sound.u_note_manager/fifo_ax_fifo_ax_0_0_s
To | g_sound.u_note_manager/scan_sel_24_s0
Launch Clk | clk_sys:[R]
Latch Clk | clk_sys:[R]

Data Arrival Path:

AT | DELAY | TYPE | RF | FANOUT | LOC | NODE
0.000 | 0.000 | | | | | active clock edge time
0.000 | 0.000 | | | | | clk_sys
0.000 | 0.000 | tCL | RR | 1 | IOB117[B] | clk_ibuf/I
1.288 | 1.288 | tINS | RR | 17271 | IOB117[B] | clk_ibuf/O
4.150 | 2.862 | tNET | RR | 16 | BSRAM_R56[11][A] | g_sound.u_note_manager/fifo_ax_fifo_ax_0_0_s/CLKB
5.959 | 1.809 | tC2Q | RR | 35 | BSRAM_R56[11][A] | g_sound.u_note_manager/fifo_ax_fifo_ax_0_0_s/DO[2]
8.563 | 2.604 | tNET | RR | 2 | R71C55[1][A] | g_sound.u_note_manager/n1777_s0/I1
9.069 | 0.506 | tINS | RF | 1 | R71C55[1][A] | g_sound.u_note_manager/n1777_s0/COUT
9.069 | 0.000 | tNET | FF | 2 | R71C55[1][B] | g_sound.u_note_manager/n1778_s0/CIN
9.114 | 0.045 | tINS | FR | 2 | R71C55[1][B] | g_sound.u_note_manager/n1778_s0/COUT
11.406 | 2.292 | tNET | RR | 1 | R37C70[3][B] | g_sound.u_note_manager/same_valid_s24/I3
11.875 | 0.469 | tINS | RR | 3 | R37C70[3][B] | g_sound.u_note_manager/same_valid_s24/F
13.024 | 1.149 | tNET | RR | 1 | R25C89[2][B] | g_sound.u_note_manager/same_valid_s11/I1
13.439 | 0.415 | tINS | RR | 3 | R25C89[2][B] | g_sound.u_note_manager/same_valid_s11/F
13.756 | 0.317 | tNET | RR | 1 | R24C90[2][A] | g_sound.u_note_manager/same_valid_s4/I0
14.221 | 0.465 | tINS | RR | 2 | R24C90[2][A] | g_sound.u_note_manager/same_valid_s4/F
14.365 | 0.144 | tNET | RR | 1 | R25C90[3][B] | g_sound.u_note_manager/same_valid_s0/I3
14.738 | 0.373 | tINS | RR | 4 | R25C90[3][B] | g_sound.u_note_manager/same_valid_s0/F
17.560 | 2.822 | tNET | RR | 1 | R61C56[0][B] | g_sound.u_note_manager/n24370_s10/I2
18.024 | 0.465 | tINS | RR | 4 | R61C56[0][B] | g_sound.u_note_manager/n24370_s10/F
18.891 | 0.866 | tNET | RR | 1 | R61C51[2][A] | g_sound.u_note_manager/n26753_s12/I1
19.127 | 0.236 | tINS | RR | 34 | R61C51[2][A] | g_sound.u_note_manager/n26753_s12/F
19.619 | 0.492 | tNET | RR | 1 | R60C52[2][A] | g_sound.u_note_manager/n26760_s11/I3
20.083 | 0.465 | tINS | RR | 1 | R60C52[2][A] | g_sound.u_note_manager/n26760_s11/F
20.083 | 0.000 | tNET | RR | 1 | R60C52[2][A] | g_sound.u_note_manager/scan_sel_24_s0/D

Data Required Path:

AT | DELAY | TYPE | RF | FANOUT | LOC | NODE
17.800 | 17.800 | | | | | active clock edge time
17.800 | 0.000 | | | | | clk_sys
17.800 | 0.000 | tCL | RR | 1 | IOB117[B] | clk_ibuf/I
19.088 | 1.288 | tINS | RR | 17271 | IOB117[B] | clk_ibuf/O
21.942 | 2.854 | tNET | RR | 1 | R60C52[2][A] | g_sound.u_note_manager/scan_sel_24_s0/CLK
21.885 | -0.057 | tSu | | 1 | R60C52[2][A] | g_sound.u_note_manager/scan_sel_24_s0

Path Statistics:

Clock Skew | -0.008
Setup Relationship | 17.800
Logic Level | 10
Arrival Clock Path Delay | cell: 1.288, 31.042%; route: 2.862, 68.958%
Arrival Data Path Delay | cell: 3.439, 21.585%; route: 10.685, 67.061%; tC2Q: 1.809, 11.354%
Required Clock Path Delay | cell: 1.288, 31.105%; route: 2.854, 68.895%

### Path16

Path Summary:

Slack | 1.867
Data Arrival Time | 20.018
Data Required Time | 21.885
From | g_sound.u_envelope_bank/dec_r_0_s0
To | g_sound.u_envelope_bank/env_level_o_249_s0
Launch Clk | clk_sys:[R]
Latch Clk | clk_sys:[R]

Data Arrival Path:

AT | DELAY | TYPE | RF | FANOUT | LOC | NODE
0.000 | 0.000 | | | | | active clock edge time
0.000 | 0.000 | | | | | clk_sys
0.000 | 0.000 | tCL | RR | 1 | IOB117[B] | clk_ibuf/I
1.288 | 1.288 | tINS | RR | 17271 | IOB117[B] | clk_ibuf/O
4.142 | 2.854 | tNET | RR | 1 | R13C95[1][A] | g_sound.u_envelope_bank/dec_r_0_s0/CLK
4.486 | 0.344 | tC2Q | RR | 2 | R13C95[1][A] | g_sound.u_envelope_bank/dec_r_0_s0/Q
5.811 | 1.325 | tNET | RR | 2 | R16C76[0][A] | g_sound.u_envelope_bank/n1798_s/I1
6.255 | 0.443 | tINS | RR | 1 | R16C76[0][A] | g_sound.u_envelope_bank/n1798_s/COUT
6.255 | 0.000 | tNET | RR | 2 | R16C76[0][B] | g_sound.u_envelope_bank/n1797_s/CIN
6.526 | 0.271 | tINS | RF | 1 | R16C76[0][B] | g_sound.u_envelope_bank/n1797_s/SUM
6.530 | 0.005 | tNET | FF | 1 | R16C76[3][A] | g_sound.u_envelope_bank/lvl_n_0_s36/I0
6.999 | 0.469 | tINS | FR | 1 | R16C76[3][A] | g_sound.u_envelope_bank/lvl_n_0_s36/F
7.141 | 0.142 | tNET | RR | 1 | R17C76[0][B] | g_sound.u_envelope_bank/lvl_n_0_s35/I2
7.606 | 0.465 | tINS | RR | 1 | R17C76[0][B] | g_sound.u_envelope_bank/lvl_n_0_s35/F
7.748 | 0.142 | tNET | RR | 1 | R16C76[3][B] | g_sound.u_envelope_bank/lvl_n_0_s34/I0
8.121 | 0.373 | tINS | RR | 1 | R16C76[3][B] | g_sound.u_envelope_bank/lvl_n_0_s34/F
8.294 | 0.173 | tNET | RR | 1 | R15C76[1][B] | g_sound.u_envelope_bank/lvl_n_0_s38/I3
8.768 | 0.474 | tINS | RR | 1 | R15C76[1][B] | g_sound.u_envelope_bank/lvl_n_0_s38/F
8.770 | 0.002 | tNET | RR | 1 | R15C76[0][B] | g_sound.u_envelope_bank/lvl_n_0_s23/I0
9.235 | 0.465 | tINS | RR | 1 | R15C76[0][B] | g_sound.u_envelope_bank/lvl_n_0_s23/F
9.548 | 0.313 | tNET | RR | 1 | R13C77[3][A] | g_sound.u_envelope_bank/lvl_n_0_s18/I0
9.786 | 0.238 | tINS | RR | 1 | R13C77[3][A] | g_sound.u_envelope_bank/lvl_n_0_s18/F
10.270 | 0.484 | tNET | RR | 1 | R9C77[1][B] | g_sound.u_envelope_bank/lvl_n_0_s15/I0
10.685 | 0.415 | tINS | RR | 10 | R9C77[1][B] | g_sound.u_envelope_bank/lvl_n_0_s15/F
11.724 | 1.039 | tNET | RR | 1 | R4C78[2][B] | g_sound.u_envelope_bank/st_n_0_s4/I1
12.140 | 0.415 | tINS | RR | 19 | R4C78[2][B] | g_sound.u_envelope_bank/st_n_0_s4/F
12.466 | 0.326 | tNET | RR | 1 | R6C77[0][A] | g_sound.u_envelope_bank/lvl_n_9_s7/I2
12.881 | 0.415 | tINS | RR | 2 | R6C77[0][A] | g_sound.u_envelope_bank/lvl_n_9_s7/F
13.196 | 0.315 | tNET | RR | 1 | R3C77[1][B] | g_sound.u_envelope_bank/lvl_n_9_s6/I3
13.611 | 0.415 | tINS | RR | 1 | R3C77[1][B] | g_sound.u_envelope_bank/lvl_n_9_s6/F
13.613 | 0.002 | tNET | RR | 1 | R3C77[0][A] | g_sound.u_envelope_bank/lvl_n_9_s3/I1
14.078 | 0.465 | tINS | RR | 1 | R3C77[0][A] | g_sound.u_envelope_bank/lvl_n_9_s3/F
14.080 | 0.002 | tNET | RR | 1 | R3C77[2][B] | g_sound.u_envelope_bank/lvl_n_9_s2/I0
14.316 | 0.236 | tINS | RR | 33 | R3C77[2][B] | g_sound.u_envelope_bank/lvl_n_9_s2/F
20.018 | 5.702 | tNET | RR | 1 | R53C70[1][A] | g_sound.u_envelope_bank/env_level_o_249_s0/D

Data Required Path:

AT | DELAY | TYPE | RF | FANOUT | LOC | NODE
17.800 | 17.800 | | | | | active clock edge time
17.800 | 0.000 | | | | | clk_sys
17.800 | 0.000 | tCL | RR | 1 | IOB117[B] | clk_ibuf/I
19.088 | 1.288 | tINS | RR | 17271 | IOB117[B] | clk_ibuf/O
21.942 | 2.854 | tNET | RR | 1 | R53C70[1][A] | g_sound.u_envelope_bank/env_level_o_249_s0/CLK
21.885 | -0.057 | tSu | | 1 | R53C70[1][A] | g_sound.u_envelope_bank/env_level_o_249_s0

Path Statistics:

Clock Skew | 0.000
Setup Relationship | 17.800
Logic Level | 15
Arrival Clock Path Delay | cell: 1.288, 31.105%; route: 2.854, 68.895%
Arrival Data Path Delay | cell: 5.560, 35.020%; route: 9.972, 62.812%; tC2Q: 0.344, 2.168%
Required Clock Path Delay | cell: 1.288, 31.105%; route: 2.854, 68.895%

### Path17

Path Summary:

Slack | 1.887
Data Arrival Time | 19.998
Data Required Time | 21.885
From | g_sound.u_note_manager/fifo_ax_fifo_ax_0_0_s
To | g_sound.u_note_manager/vtgt_vld_vtgt_vld_RAMREG_12_G[0]_s0
Launch Clk | clk_sys:[R]
Latch Clk | clk_sys:[R]

Data Arrival Path:

AT | DELAY | TYPE | RF | FANOUT | LOC | NODE
0.000 | 0.000 | | | | | active clock edge time
0.000 | 0.000 | | | | | clk_sys
0.000 | 0.000 | tCL | RR | 1 | IOB117[B] | clk_ibuf/I
1.288 | 1.288 | tINS | RR | 17271 | IOB117[B] | clk_ibuf/O
4.150 | 2.862 | tNET | RR | 16 | BSRAM_R56[11][A] | g_sound.u_note_manager/fifo_ax_fifo_ax_0_0_s/CLKB
5.959 | 1.809 | tC2Q | RR | 35 | BSRAM_R56[11][A] | g_sound.u_note_manager/fifo_ax_fifo_ax_0_0_s/DO[2]
8.563 | 2.604 | tNET | RR | 2 | R71C55[1][A] | g_sound.u_note_manager/n1777_s0/I1
9.069 | 0.506 | tINS | RF | 1 | R71C55[1][A] | g_sound.u_note_manager/n1777_s0/COUT
9.069 | 0.000 | tNET | FF | 2 | R71C55[1][B] | g_sound.u_note_manager/n1778_s0/CIN
9.114 | 0.045 | tINS | FR | 2 | R71C55[1][B] | g_sound.u_note_manager/n1778_s0/COUT
11.406 | 2.292 | tNET | RR | 1 | R37C70[3][B] | g_sound.u_note_manager/same_valid_s24/I3
11.875 | 0.469 | tINS | RR | 3 | R37C70[3][B] | g_sound.u_note_manager/same_valid_s24/F
13.024 | 1.149 | tNET | RR | 1 | R25C89[2][B] | g_sound.u_note_manager/same_valid_s11/I1
13.439 | 0.415 | tINS | RR | 3 | R25C89[2][B] | g_sound.u_note_manager/same_valid_s11/F
13.756 | 0.317 | tNET | RR | 1 | R24C90[2][A] | g_sound.u_note_manager/same_valid_s4/I0
14.221 | 0.465 | tINS | RR | 2 | R24C90[2][A] | g_sound.u_note_manager/same_valid_s4/F
14.365 | 0.144 | tNET | RR | 1 | R25C90[3][B] | g_sound.u_note_manager/same_valid_s0/I3
14.738 | 0.373 | tINS | RR | 4 | R25C90[3][B] | g_sound.u_note_manager/same_valid_s0/F
17.560 | 2.822 | tNET | RR | 1 | R61C56[0][B] | g_sound.u_note_manager/n24370_s10/I2
18.024 | 0.465 | tINS | RR | 4 | R61C56[0][B] | g_sound.u_note_manager/n24370_s10/F
18.168 | 0.144 | tNET | RR | 1 | R62C56[0][A] | g_sound.u_note_manager/vtgt_vld_s371/I1
18.380 | 0.211 | tINS | RF | 16 | R62C56[0][A] | g_sound.u_note_manager/vtgt_vld_s371/F
19.761 | 1.382 | tNET | FF | 1 | R63C68[0][A] | g_sound.u_note_manager/vtgt_vld_s360/I0
19.998 | 0.236 | tINS | FR | 1 | R63C68[0][A] | g_sound.u_note_manager/vtgt_vld_s360/F
19.998 | 0.000 | tNET | RR | 1 | R63C68[0][A] | g_sound.u_note_manager/vtgt_vld_vtgt_vld_RAMREG_12_G[0]_s0/D

Data Required Path:

AT | DELAY | TYPE | RF | FANOUT | LOC | NODE
17.800 | 17.800 | | | | | active clock edge time
17.800 | 0.000 | | | | | clk_sys
17.800 | 0.000 | tCL | RR | 1 | IOB117[B] | clk_ibuf/I
19.088 | 1.288 | tINS | RR | 17271 | IOB117[B] | clk_ibuf/O
21.942 | 2.854 | tNET | RR | 1 | R63C68[0][A] | g_sound.u_note_manager/vtgt_vld_vtgt_vld_RAMREG_12_G[0]_s0/CLK
21.885 | -0.057 | tSu | | 1 | R63C68[0][A] | g_sound.u_note_manager/vtgt_vld_vtgt_vld_RAMREG_12_G[0]_s0

Path Statistics:

Clock Skew | -0.008
Setup Relationship | 17.800
Logic Level | 10
Arrival Clock Path Delay | cell: 1.288, 31.042%; route: 2.862, 68.958%
Arrival Data Path Delay | cell: 3.186, 20.104%; route: 10.852, 68.480%; tC2Q: 1.809, 11.415%
Required Clock Path Delay | cell: 1.288, 31.105%; route: 2.854, 68.895%

### Path18

Path Summary:

Slack | 1.891
Data Arrival Time | 20.002
Data Required Time | 21.893
From | g_sound.u_envelope_bank/dec_r_0_s0
To | g_sound.u_envelope_bank/env_level_o_433_s0
Launch Clk | clk_sys:[R]
Latch Clk | clk_sys:[R]

Data Arrival Path:

AT | DELAY | TYPE | RF | FANOUT | LOC | NODE
0.000 | 0.000 | | | | | active clock edge time
0.000 | 0.000 | | | | | clk_sys
0.000 | 0.000 | tCL | RR | 1 | IOB117[B] | clk_ibuf/I
1.288 | 1.288 | tINS | RR | 17271 | IOB117[B] | clk_ibuf/O
4.142 | 2.854 | tNET | RR | 1 | R13C95[1][A] | g_sound.u_envelope_bank/dec_r_0_s0/CLK
4.486 | 0.344 | tC2Q | RR | 2 | R13C95[1][A] | g_sound.u_envelope_bank/dec_r_0_s0/Q
5.811 | 1.325 | tNET | RR | 2 | R16C76[0][A] | g_sound.u_envelope_bank/n1798_s/I1
6.255 | 0.443 | tINS | RR | 1 | R16C76[0][A] | g_sound.u_envelope_bank/n1798_s/COUT
6.255 | 0.000 | tNET | RR | 2 | R16C76[0][B] | g_sound.u_envelope_bank/n1797_s/CIN
6.526 | 0.271 | tINS | RF | 1 | R16C76[0][B] | g_sound.u_envelope_bank/n1797_s/SUM
6.530 | 0.005 | tNET | FF | 1 | R16C76[3][A] | g_sound.u_envelope_bank/lvl_n_0_s36/I0
6.999 | 0.469 | tINS | FR | 1 | R16C76[3][A] | g_sound.u_envelope_bank/lvl_n_0_s36/F
7.141 | 0.142 | tNET | RR | 1 | R17C76[0][B] | g_sound.u_envelope_bank/lvl_n_0_s35/I2
7.606 | 0.465 | tINS | RR | 1 | R17C76[0][B] | g_sound.u_envelope_bank/lvl_n_0_s35/F
7.748 | 0.142 | tNET | RR | 1 | R16C76[3][B] | g_sound.u_envelope_bank/lvl_n_0_s34/I0
8.121 | 0.373 | tINS | RR | 1 | R16C76[3][B] | g_sound.u_envelope_bank/lvl_n_0_s34/F
8.294 | 0.173 | tNET | RR | 1 | R15C76[1][B] | g_sound.u_envelope_bank/lvl_n_0_s38/I3
8.768 | 0.474 | tINS | RR | 1 | R15C76[1][B] | g_sound.u_envelope_bank/lvl_n_0_s38/F
8.770 | 0.002 | tNET | RR | 1 | R15C76[0][B] | g_sound.u_envelope_bank/lvl_n_0_s23/I0
9.235 | 0.465 | tINS | RR | 1 | R15C76[0][B] | g_sound.u_envelope_bank/lvl_n_0_s23/F
9.548 | 0.313 | tNET | RR | 1 | R13C77[3][A] | g_sound.u_envelope_bank/lvl_n_0_s18/I0
9.786 | 0.238 | tINS | RR | 1 | R13C77[3][A] | g_sound.u_envelope_bank/lvl_n_0_s18/F
10.270 | 0.484 | tNET | RR | 1 | R9C77[1][B] | g_sound.u_envelope_bank/lvl_n_0_s15/I0
10.685 | 0.415 | tINS | RR | 10 | R9C77[1][B] | g_sound.u_envelope_bank/lvl_n_0_s15/F
11.724 | 1.039 | tNET | RR | 1 | R4C78[2][B] | g_sound.u_envelope_bank/st_n_0_s4/I1
12.140 | 0.415 | tINS | RR | 19 | R4C78[2][B] | g_sound.u_envelope_bank/st_n_0_s4/F
13.035 | 0.896 | tNET | RR | 1 | R13C82[2][A] | g_sound.u_envelope_bank/lvl_n_1_s10/I2
13.500 | 0.465 | tINS | RR | 1 | R13C82[2][A] | g_sound.u_envelope_bank/lvl_n_1_s10/F
13.502 | 0.002 | tNET | RR | 1 | R13C82[1][B] | g_sound.u_envelope_bank/lvl_n_1_s5/I0
13.917 | 0.415 | tINS | RR | 1 | R13C82[1][B] | g_sound.u_envelope_bank/lvl_n_1_s5/F
14.059 | 0.142 | tNET | RR | 1 | R14C82[1][B] | g_sound.u_envelope_bank/lvl_n_1_s2/I2
14.295 | 0.236 | tINS | RR | 33 | R14C82[1][B] | g_sound.u_envelope_bank/lvl_n_1_s2/F
20.002 | 5.707 | tNET | RR | 1 | R45C51[2][A] | g_sound.u_envelope_bank/env_level_o_433_s0/D

Data Required Path:

AT | DELAY | TYPE | RF | FANOUT | LOC | NODE
17.800 | 17.800 | | | | | active clock edge time
17.800 | 0.000 | | | | | clk_sys
17.800 | 0.000 | tCL | RR | 1 | IOB117[B] | clk_ibuf/I
19.088 | 1.288 | tINS | RR | 17271 | IOB117[B] | clk_ibuf/O
21.950 | 2.862 | tNET | RR | 1 | R45C51[2][A] | g_sound.u_envelope_bank/env_level_o_433_s0/CLK
21.893 | -0.057 | tSu | | 1 | R45C51[2][A] | g_sound.u_envelope_bank/env_level_o_433_s0

Path Statistics:

Clock Skew | 0.008
Setup Relationship | 17.800
Logic Level | 14
Arrival Clock Path Delay | cell: 1.288, 31.105%; route: 2.854, 68.895%
Arrival Data Path Delay | cell: 5.145, 32.437%; route: 10.371, 65.392%; tC2Q: 0.344, 2.171%
Required Clock Path Delay | cell: 1.288, 31.042%; route: 2.862, 68.958%

### Path19

Path Summary:

Slack | 1.927
Data Arrival Time | 16.614
Data Required Time | 18.541
From | g_sound.u_adc_farm/u_scan0/sample_channel_0_s0
To | g_sound.u_calib1/n909_s
Launch Clk | clk_sys:[R]
Latch Clk | clk_sys:[R]

Data Arrival Path:

AT | DELAY | TYPE | RF | FANOUT | LOC | NODE
0.000 | 0.000 | | | | | active clock edge time
0.000 | 0.000 | | | | | clk_sys
0.000 | 0.000 | tCL | RR | 1 | IOB117[B] | clk_ibuf/I
1.288 | 1.288 | tINS | RR | 17271 | IOB117[B] | clk_ibuf/O
4.150 | 2.862 | tNET | RR | 1 | R71C128[1][A] | g_sound.u_adc_farm/u_scan0/sample_channel_0_s0/CLK
4.481 | 0.331 | tC2Q | RF | 146 | R71C128[1][A] | g_sound.u_adc_farm/u_scan0/sample_channel_0_s0/Q
8.449 | 3.968 | tNET | FF | 1 | R61C102[2][B] | g_sound.u_calib1/n64_s19/I2
8.864 | 0.415 | tINS | FR | 1 | R61C102[2][B] | g_sound.u_calib1/n64_s19/F
8.864 | 0.000 | tNET | RR | 1 | R61C102[2][A] | g_sound.u_calib1/n64_s15/I1
8.987 | 0.123 | tINS | RR | 1 | R61C102[2][A] | g_sound.u_calib1/n64_s15/O
8.987 | 0.000 | tNET | RR | 1 | R61C102[2][B] | g_sound.u_calib1/n64_s13/I1
9.064 | 0.078 | tINS | RR | 1 | R61C102[2][B] | g_sound.u_calib1/n64_s13/O
9.725 | 0.660 | tNET | RR | 1 | R70C103[0][B] | g_sound.u_calib1/dclamp_9_s7/I3
10.189 | 0.465 | tINS | RR | 1 | R70C103[0][B] | g_sound.u_calib1/dclamp_9_s7/F
10.534 | 0.344 | tNET | RR | 1 | R68C102[3][B] | g_sound.u_calib1/dclamp_9_s4/I3
11.003 | 0.469 | tINS | RR | 16 | R68C102[3][B] | g_sound.u_calib1/dclamp_9_s4/F
11.651 | 0.648 | tNET | RR | 1 | R72C103[1][A] | g_sound.u_calib1/dclamp_8_s17/I3
11.887 | 0.236 | tINS | RR | 1 | R72C103[1][A] | g_sound.u_calib1/dclamp_8_s17/F
12.029 | 0.142 | tNET | RR | 1 | R72C104[3][B] | g_sound.u_calib1/dclamp_8_s20/I1
12.402 | 0.373 | tINS | RR | 1 | R72C104[3][B] | g_sound.u_calib1/dclamp_8_s20/F
12.526 | 0.124 | tNET | RR | 1 | R72C104[1][B] | g_sound.u_calib1/dclamp_8_s15/I2
12.762 | 0.236 | tINS | RR | 1 | R72C104[1][B] | g_sound.u_calib1/dclamp_8_s15/F
12.935 | 0.173 | tNET | RR | 1 | R72C106[1][B] | g_sound.u_calib1/dclamp_8_s13/I3
13.400 | 0.465 | tINS | RR | 2 | R72C106[1][B] | g_sound.u_calib1/dclamp_8_s13/F
13.544 | 0.144 | tNET | RR | 1 | R72C105[2][A] | g_sound.u_calib1/dclamp_8_s12/I3
13.780 | 0.236 | tINS | RR | 1 | R72C105[2][A] | g_sound.u_calib1/dclamp_8_s12/F
13.783 | 0.002 | tNET | RR | 1 | R72C105[1][A] | g_sound.u_calib1/dclamp_8_s7/I3
14.198 | 0.415 | tINS | RR | 2 | R72C105[1][A] | g_sound.u_calib1/dclamp_8_s7/F
14.513 | 0.315 | tNET | RR | 1 | R71C104[0][B] | g_sound.u_calib1/dclamp_8_s4/I3
14.749 | 0.236 | tINS | RR | 8 | R71C104[0][B] | g_sound.u_calib1/dclamp_8_s4/F
15.440 | 0.691 | tNET | RR | 1 | R72C101[2][A] | g_sound.u_calib1/dclamp_2_s0/I1
15.855 | 0.415 | tINS | RR | 1 | R72C101[2][A] | g_sound.u_calib1/dclamp_2_s0/F
16.614 | 0.759 | tNET | RR | 1 | DSP_R65[33] | g_sound.u_calib1/n909_s/A[2]

Data Required Path:

AT | DELAY | TYPE | RF | FANOUT | LOC | NODE
17.800 | 17.800 | | | | | active clock edge time
17.800 | 0.000 | | | | | clk_sys
17.800 | 0.000 | tCL | RR | 1 | IOB117[B] | clk_ibuf/I
19.088 | 1.288 | tINS | RR | 17271 | IOB117[B] | clk_ibuf/O
21.942 | 2.854 | tNET | RR | 1 | DSP_R65[33] | g_sound.u_calib1/n909_s/CLK[0]
18.541 | -3.401 | tSu | | 1 | DSP_R65[33] | g_sound.u_calib1/n909_s

Path Statistics:

Clock Skew | -0.008
Setup Relationship | 17.800
Logic Level | 12
Arrival Clock Path Delay | cell: 1.288, 31.042%; route: 2.862, 68.958%
Arrival Data Path Delay | cell: 4.162, 33.397%; route: 7.971, 63.950%; tC2Q: 0.331, 2.654%
Required Clock Path Delay | cell: 1.288, 31.105%; route: 2.854, 68.895%

### Path20

Path Summary:

Slack | 1.936
Data Arrival Time | 19.948
Data Required Time | 21.885
From | g_sound.u_note_manager/fifo_ax_fifo_ax_0_0_s
To | g_sound.u_note_manager/scan_sel_25_s0
Launch Clk | clk_sys:[R]
Latch Clk | clk_sys:[R]

Data Arrival Path:

AT | DELAY | TYPE | RF | FANOUT | LOC | NODE
0.000 | 0.000 | | | | | active clock edge time
0.000 | 0.000 | | | | | clk_sys
0.000 | 0.000 | tCL | RR | 1 | IOB117[B] | clk_ibuf/I
1.288 | 1.288 | tINS | RR | 17271 | IOB117[B] | clk_ibuf/O
4.150 | 2.862 | tNET | RR | 16 | BSRAM_R56[11][A] | g_sound.u_note_manager/fifo_ax_fifo_ax_0_0_s/CLKB
5.959 | 1.809 | tC2Q | RR | 35 | BSRAM_R56[11][A] | g_sound.u_note_manager/fifo_ax_fifo_ax_0_0_s/DO[2]
8.563 | 2.604 | tNET | RR | 2 | R71C55[1][A] | g_sound.u_note_manager/n1777_s0/I1
9.069 | 0.506 | tINS | RF | 1 | R71C55[1][A] | g_sound.u_note_manager/n1777_s0/COUT
9.069 | 0.000 | tNET | FF | 2 | R71C55[1][B] | g_sound.u_note_manager/n1778_s0/CIN
9.114 | 0.045 | tINS | FR | 2 | R71C55[1][B] | g_sound.u_note_manager/n1778_s0/COUT
11.406 | 2.292 | tNET | RR | 1 | R37C70[3][B] | g_sound.u_note_manager/same_valid_s24/I3
11.875 | 0.469 | tINS | RR | 3 | R37C70[3][B] | g_sound.u_note_manager/same_valid_s24/F
13.024 | 1.149 | tNET | RR | 1 | R25C89[2][B] | g_sound.u_note_manager/same_valid_s11/I1
13.439 | 0.415 | tINS | RR | 3 | R25C89[2][B] | g_sound.u_note_manager/same_valid_s11/F
13.756 | 0.317 | tNET | RR | 1 | R24C90[2][A] | g_sound.u_note_manager/same_valid_s4/I0
14.221 | 0.465 | tINS | RR | 2 | R24C90[2][A] | g_sound.u_note_manager/same_valid_s4/F
14.365 | 0.144 | tNET | RR | 1 | R25C90[3][B] | g_sound.u_note_manager/same_valid_s0/I3
14.738 | 0.373 | tINS | RR | 4 | R25C90[3][B] | g_sound.u_note_manager/same_valid_s0/F
17.560 | 2.822 | tNET | RR | 1 | R61C56[0][B] | g_sound.u_note_manager/n24370_s10/I2
18.024 | 0.465 | tINS | RR | 4 | R61C56[0][B] | g_sound.u_note_manager/n24370_s10/F
18.891 | 0.866 | tNET | RR | 1 | R61C51[2][A] | g_sound.u_note_manager/n26753_s12/I1
19.102 | 0.211 | tINS | RF | 34 | R61C51[2][A] | g_sound.u_note_manager/n26753_s12/F
19.533 | 0.431 | tNET | FF | 1 | R60C52[2][B] | g_sound.u_note_manager/n26759_s11/I3
19.948 | 0.415 | tINS | FR | 1 | R60C52[2][B] | g_sound.u_note_manager/n26759_s11/F
19.948 | 0.000 | tNET | RR | 1 | R60C52[2][B] | g_sound.u_note_manager/scan_sel_25_s0/D

Data Required Path:

AT | DELAY | TYPE | RF | FANOUT | LOC | NODE
17.800 | 17.800 | | | | | active clock edge time
17.800 | 0.000 | | | | | clk_sys
17.800 | 0.000 | tCL | RR | 1 | IOB117[B] | clk_ibuf/I
19.088 | 1.288 | tINS | RR | 17271 | IOB117[B] | clk_ibuf/O
21.942 | 2.854 | tNET | RR | 1 | R60C52[2][B] | g_sound.u_note_manager/scan_sel_25_s0/CLK
21.885 | -0.057 | tSu | | 1 | R60C52[2][B] | g_sound.u_note_manager/scan_sel_25_s0

Path Statistics:

Clock Skew | -0.008
Setup Relationship | 17.800
Logic Level | 10
Arrival Clock Path Delay | cell: 1.288, 31.042%; route: 2.862, 68.958%
Arrival Data Path Delay | cell: 3.365, 21.300%; route: 10.624, 67.249%; tC2Q: 1.809, 11.451%
Required Clock Path Delay | cell: 1.288, 31.105%; route: 2.854, 68.895%

### Path21

Path Summary:

Slack | 1.958
Data Arrival Time | 19.927
Data Required Time | 21.885
From | g_sound.u_note_manager/fifo_ax_fifo_ax_0_0_s
To | g_sound.u_note_manager/scan_sel_22_s0
Launch Clk | clk_sys:[R]
Latch Clk | clk_sys:[R]

Data Arrival Path:

AT | DELAY | TYPE | RF | FANOUT | LOC | NODE
0.000 | 0.000 | | | | | active clock edge time
0.000 | 0.000 | | | | | clk_sys
0.000 | 0.000 | tCL | RR | 1 | IOB117[B] | clk_ibuf/I
1.288 | 1.288 | tINS | RR | 17271 | IOB117[B] | clk_ibuf/O
4.150 | 2.862 | tNET | RR | 16 | BSRAM_R56[11][A] | g_sound.u_note_manager/fifo_ax_fifo_ax_0_0_s/CLKB
5.959 | 1.809 | tC2Q | RR | 35 | BSRAM_R56[11][A] | g_sound.u_note_manager/fifo_ax_fifo_ax_0_0_s/DO[2]
8.563 | 2.604 | tNET | RR | 2 | R71C55[1][A] | g_sound.u_note_manager/n1777_s0/I1
9.069 | 0.506 | tINS | RF | 1 | R71C55[1][A] | g_sound.u_note_manager/n1777_s0/COUT
9.069 | 0.000 | tNET | FF | 2 | R71C55[1][B] | g_sound.u_note_manager/n1778_s0/CIN
9.114 | 0.045 | tINS | FR | 2 | R71C55[1][B] | g_sound.u_note_manager/n1778_s0/COUT
11.406 | 2.292 | tNET | RR | 1 | R37C70[3][B] | g_sound.u_note_manager/same_valid_s24/I3
11.875 | 0.469 | tINS | RR | 3 | R37C70[3][B] | g_sound.u_note_manager/same_valid_s24/F
13.024 | 1.149 | tNET | RR | 1 | R25C89[2][B] | g_sound.u_note_manager/same_valid_s11/I1
13.439 | 0.415 | tINS | RR | 3 | R25C89[2][B] | g_sound.u_note_manager/same_valid_s11/F
13.756 | 0.317 | tNET | RR | 1 | R24C90[2][A] | g_sound.u_note_manager/same_valid_s4/I0
14.221 | 0.465 | tINS | RR | 2 | R24C90[2][A] | g_sound.u_note_manager/same_valid_s4/F
14.365 | 0.144 | tNET | RR | 1 | R25C90[3][B] | g_sound.u_note_manager/same_valid_s0/I3
14.738 | 0.373 | tINS | RR | 4 | R25C90[3][B] | g_sound.u_note_manager/same_valid_s0/F
17.560 | 2.822 | tNET | RR | 1 | R61C56[0][B] | g_sound.u_note_manager/n24370_s10/I2
18.024 | 0.465 | tINS | RR | 4 | R61C56[0][B] | g_sound.u_note_manager/n24370_s10/F
18.891 | 0.866 | tNET | RR | 1 | R61C51[2][A] | g_sound.u_note_manager/n26753_s12/I1
19.102 | 0.211 | tINS | RF | 34 | R61C51[2][A] | g_sound.u_note_manager/n26753_s12/F
19.512 | 0.410 | tNET | FF | 1 | R60C52[1][A] | g_sound.u_note_manager/n26762_s11/I3
19.927 | 0.415 | tINS | FR | 1 | R60C52[1][A] | g_sound.u_note_manager/n26762_s11/F
19.927 | 0.000 | tNET | RR | 1 | R60C52[1][A] | g_sound.u_note_manager/scan_sel_22_s0/D

Data Required Path:

AT | DELAY | TYPE | RF | FANOUT | LOC | NODE
17.800 | 17.800 | | | | | active clock edge time
17.800 | 0.000 | | | | | clk_sys
17.800 | 0.000 | tCL | RR | 1 | IOB117[B] | clk_ibuf/I
19.088 | 1.288 | tINS | RR | 17271 | IOB117[B] | clk_ibuf/O
21.942 | 2.854 | tNET | RR | 1 | R60C52[1][A] | g_sound.u_note_manager/scan_sel_22_s0/CLK
21.885 | -0.057 | tSu | | 1 | R60C52[1][A] | g_sound.u_note_manager/scan_sel_22_s0

Path Statistics:

Clock Skew | -0.008
Setup Relationship | 17.800
Logic Level | 10
Arrival Clock Path Delay | cell: 1.288, 31.042%; route: 2.862, 68.958%
Arrival Data Path Delay | cell: 3.365, 21.328%; route: 10.603, 67.205%; tC2Q: 1.809, 11.466%
Required Clock Path Delay | cell: 1.288, 31.105%; route: 2.854, 68.895%

### Path22

Path Summary:

Slack | 1.969
Data Arrival Time | 16.679
Data Required Time | 18.648
From | g_sound.u_adc_farm/u_scan0/sample_channel_0_s0
To | g_sound.u_calib1/n909_s
Launch Clk | clk_sys:[R]
Latch Clk | clk_sys:[R]

Data Arrival Path:

AT | DELAY | TYPE | RF | FANOUT | LOC | NODE
0.000 | 0.000 | | | | | active clock edge time
0.000 | 0.000 | | | | | clk_sys
0.000 | 0.000 | tCL | RR | 1 | IOB117[B] | clk_ibuf/I
1.288 | 1.288 | tINS | RR | 17271 | IOB117[B] | clk_ibuf/O
4.150 | 2.862 | tNET | RR | 1 | R71C128[1][A] | g_sound.u_adc_farm/u_scan0/sample_channel_0_s0/CLK
4.481 | 0.331 | tC2Q | RF | 146 | R71C128[1][A] | g_sound.u_adc_farm/u_scan0/sample_channel_0_s0/Q
8.449 | 3.968 | tNET | FF | 1 | R61C102[2][B] | g_sound.u_calib1/n64_s19/I2
8.864 | 0.415 | tINS | FR | 1 | R61C102[2][B] | g_sound.u_calib1/n64_s19/F
8.864 | 0.000 | tNET | RR | 1 | R61C102[2][A] | g_sound.u_calib1/n64_s15/I1
8.987 | 0.123 | tINS | RR | 1 | R61C102[2][A] | g_sound.u_calib1/n64_s15/O
8.987 | 0.000 | tNET | RR | 1 | R61C102[2][B] | g_sound.u_calib1/n64_s13/I1
9.064 | 0.078 | tINS | RR | 1 | R61C102[2][B] | g_sound.u_calib1/n64_s13/O
9.725 | 0.660 | tNET | RR | 1 | R70C103[0][B] | g_sound.u_calib1/dclamp_9_s7/I3
10.189 | 0.465 | tINS | RR | 1 | R70C103[0][B] | g_sound.u_calib1/dclamp_9_s7/F
10.534 | 0.344 | tNET | RR | 1 | R68C102[3][B] | g_sound.u_calib1/dclamp_9_s4/I3
11.003 | 0.469 | tINS | RR | 16 | R68C102[3][B] | g_sound.u_calib1/dclamp_9_s4/F
11.651 | 0.648 | tNET | RR | 1 | R72C103[1][A] | g_sound.u_calib1/dclamp_8_s17/I3
11.887 | 0.236 | tINS | RR | 1 | R72C103[1][A] | g_sound.u_calib1/dclamp_8_s17/F
12.029 | 0.142 | tNET | RR | 1 | R72C104[3][B] | g_sound.u_calib1/dclamp_8_s20/I1
12.402 | 0.373 | tINS | RR | 1 | R72C104[3][B] | g_sound.u_calib1/dclamp_8_s20/F
12.526 | 0.124 | tNET | RR | 1 | R72C104[1][B] | g_sound.u_calib1/dclamp_8_s15/I2
12.762 | 0.236 | tINS | RR | 1 | R72C104[1][B] | g_sound.u_calib1/dclamp_8_s15/F
12.935 | 0.173 | tNET | RR | 1 | R72C106[1][B] | g_sound.u_calib1/dclamp_8_s13/I3
13.400 | 0.465 | tINS | RR | 2 | R72C106[1][B] | g_sound.u_calib1/dclamp_8_s13/F
13.544 | 0.144 | tNET | RR | 1 | R72C105[2][A] | g_sound.u_calib1/dclamp_8_s12/I3
13.780 | 0.236 | tINS | RR | 1 | R72C105[2][A] | g_sound.u_calib1/dclamp_8_s12/F
13.783 | 0.002 | tNET | RR | 1 | R72C105[1][A] | g_sound.u_calib1/dclamp_8_s7/I3
14.198 | 0.415 | tINS | RR | 2 | R72C105[1][A] | g_sound.u_calib1/dclamp_8_s7/F
14.513 | 0.315 | tNET | RR | 1 | R71C104[0][B] | g_sound.u_calib1/dclamp_8_s4/I3
14.749 | 0.236 | tINS | RR | 8 | R71C104[0][B] | g_sound.u_calib1/dclamp_8_s4/F
15.390 | 0.641 | tNET | RR | 1 | R71C101[0][B] | g_sound.u_calib1/dclamp_4_s0/I1
15.855 | 0.465 | tINS | RR | 1 | R71C101[0][B] | g_sound.u_calib1/dclamp_4_s0/F
16.679 | 0.825 | tNET | RR | 1 | DSP_R65[33] | g_sound.u_calib1/n909_s/A[4]

Data Required Path:

AT | DELAY | TYPE | RF | FANOUT | LOC | NODE
17.800 | 17.800 | | | | | active clock edge time
17.800 | 0.000 | | | | | clk_sys
17.800 | 0.000 | tCL | RR | 1 | IOB117[B] | clk_ibuf/I
19.088 | 1.288 | tINS | RR | 17271 | IOB117[B] | clk_ibuf/O
21.942 | 2.854 | tNET | RR | 1 | DSP_R65[33] | g_sound.u_calib1/n909_s/CLK[0]
18.648 | -3.294 | tSu | | 1 | DSP_R65[33] | g_sound.u_calib1/n909_s

Path Statistics:

Clock Skew | -0.008
Setup Relationship | 17.800
Logic Level | 12
Arrival Clock Path Delay | cell: 1.288, 31.042%; route: 2.862, 68.958%
Arrival Data Path Delay | cell: 4.212, 33.618%; route: 7.986, 63.742%; tC2Q: 0.331, 2.640%
Required Clock Path Delay | cell: 1.288, 31.105%; route: 2.854, 68.895%

### Path23

Path Summary:

Slack | 1.978
Data Arrival Time | 19.907
Data Required Time | 21.885
From | g_sound.u_note_manager/fifo_ax_fifo_ax_0_0_s
To | g_sound.u_note_manager/scan_sel_26_s0
Launch Clk | clk_sys:[R]
Latch Clk | clk_sys:[R]

Data Arrival Path:

AT | DELAY | TYPE | RF | FANOUT | LOC | NODE
0.000 | 0.000 | | | | | active clock edge time
0.000 | 0.000 | | | | | clk_sys
0.000 | 0.000 | tCL | RR | 1 | IOB117[B] | clk_ibuf/I
1.288 | 1.288 | tINS | RR | 17271 | IOB117[B] | clk_ibuf/O
4.150 | 2.862 | tNET | RR | 16 | BSRAM_R56[11][A] | g_sound.u_note_manager/fifo_ax_fifo_ax_0_0_s/CLKB
5.959 | 1.809 | tC2Q | RR | 35 | BSRAM_R56[11][A] | g_sound.u_note_manager/fifo_ax_fifo_ax_0_0_s/DO[2]
8.563 | 2.604 | tNET | RR | 2 | R71C55[1][A] | g_sound.u_note_manager/n1777_s0/I1
9.069 | 0.506 | tINS | RF | 1 | R71C55[1][A] | g_sound.u_note_manager/n1777_s0/COUT
9.069 | 0.000 | tNET | FF | 2 | R71C55[1][B] | g_sound.u_note_manager/n1778_s0/CIN
9.114 | 0.045 | tINS | FR | 2 | R71C55[1][B] | g_sound.u_note_manager/n1778_s0/COUT
11.406 | 2.292 | tNET | RR | 1 | R37C70[3][B] | g_sound.u_note_manager/same_valid_s24/I3
11.875 | 0.469 | tINS | RR | 3 | R37C70[3][B] | g_sound.u_note_manager/same_valid_s24/F
13.024 | 1.149 | tNET | RR | 1 | R25C89[2][B] | g_sound.u_note_manager/same_valid_s11/I1
13.439 | 0.415 | tINS | RR | 3 | R25C89[2][B] | g_sound.u_note_manager/same_valid_s11/F
13.756 | 0.317 | tNET | RR | 1 | R24C90[2][A] | g_sound.u_note_manager/same_valid_s4/I0
14.221 | 0.465 | tINS | RR | 2 | R24C90[2][A] | g_sound.u_note_manager/same_valid_s4/F
14.365 | 0.144 | tNET | RR | 1 | R25C90[3][B] | g_sound.u_note_manager/same_valid_s0/I3
14.738 | 0.373 | tINS | RR | 4 | R25C90[3][B] | g_sound.u_note_manager/same_valid_s0/F
17.560 | 2.822 | tNET | RR | 1 | R61C56[0][B] | g_sound.u_note_manager/n24370_s10/I2
18.024 | 0.465 | tINS | RR | 4 | R61C56[0][B] | g_sound.u_note_manager/n24370_s10/F
18.891 | 0.866 | tNET | RR | 1 | R61C51[2][A] | g_sound.u_note_manager/n26753_s12/I1
19.102 | 0.211 | tINS | RF | 34 | R61C51[2][A] | g_sound.u_note_manager/n26753_s12/F
19.533 | 0.431 | tNET | FF | 1 | R60C52[3][A] | g_sound.u_note_manager/n26758_s11/I3
19.907 | 0.373 | tINS | FR | 1 | R60C52[3][A] | g_sound.u_note_manager/n26758_s11/F
19.907 | 0.000 | tNET | RR | 1 | R60C52[3][A] | g_sound.u_note_manager/scan_sel_26_s0/D

Data Required Path:

AT | DELAY | TYPE | RF | FANOUT | LOC | NODE
17.800 | 17.800 | | | | | active clock edge time
17.800 | 0.000 | | | | | clk_sys
17.800 | 0.000 | tCL | RR | 1 | IOB117[B] | clk_ibuf/I
19.088 | 1.288 | tINS | RR | 17271 | IOB117[B] | clk_ibuf/O
21.942 | 2.854 | tNET | RR | 1 | R60C52[3][A] | g_sound.u_note_manager/scan_sel_26_s0/CLK
21.885 | -0.057 | tSu | | 1 | R60C52[3][A] | g_sound.u_note_manager/scan_sel_26_s0

Path Statistics:

Clock Skew | -0.008
Setup Relationship | 17.800
Logic Level | 10
Arrival Clock Path Delay | cell: 1.288, 31.042%; route: 2.862, 68.958%
Arrival Data Path Delay | cell: 3.323, 21.092%; route: 10.624, 67.427%; tC2Q: 1.809, 11.481%
Required Clock Path Delay | cell: 1.288, 31.105%; route: 2.854, 68.895%

### Path24

Path Summary:

Slack | 1.978
Data Arrival Time | 19.907
Data Required Time | 21.885
From | g_sound.u_note_manager/fifo_ax_fifo_ax_0_0_s
To | g_sound.u_note_manager/scan_sel_27_s0
Launch Clk | clk_sys:[R]
Latch Clk | clk_sys:[R]

Data Arrival Path:

AT | DELAY | TYPE | RF | FANOUT | LOC | NODE
0.000 | 0.000 | | | | | active clock edge time
0.000 | 0.000 | | | | | clk_sys
0.000 | 0.000 | tCL | RR | 1 | IOB117[B] | clk_ibuf/I
1.288 | 1.288 | tINS | RR | 17271 | IOB117[B] | clk_ibuf/O
4.150 | 2.862 | tNET | RR | 16 | BSRAM_R56[11][A] | g_sound.u_note_manager/fifo_ax_fifo_ax_0_0_s/CLKB
5.959 | 1.809 | tC2Q | RR | 35 | BSRAM_R56[11][A] | g_sound.u_note_manager/fifo_ax_fifo_ax_0_0_s/DO[2]
8.563 | 2.604 | tNET | RR | 2 | R71C55[1][A] | g_sound.u_note_manager/n1777_s0/I1
9.069 | 0.506 | tINS | RF | 1 | R71C55[1][A] | g_sound.u_note_manager/n1777_s0/COUT
9.069 | 0.000 | tNET | FF | 2 | R71C55[1][B] | g_sound.u_note_manager/n1778_s0/CIN
9.114 | 0.045 | tINS | FR | 2 | R71C55[1][B] | g_sound.u_note_manager/n1778_s0/COUT
11.406 | 2.292 | tNET | RR | 1 | R37C70[3][B] | g_sound.u_note_manager/same_valid_s24/I3
11.875 | 0.469 | tINS | RR | 3 | R37C70[3][B] | g_sound.u_note_manager/same_valid_s24/F
13.024 | 1.149 | tNET | RR | 1 | R25C89[2][B] | g_sound.u_note_manager/same_valid_s11/I1
13.439 | 0.415 | tINS | RR | 3 | R25C89[2][B] | g_sound.u_note_manager/same_valid_s11/F
13.756 | 0.317 | tNET | RR | 1 | R24C90[2][A] | g_sound.u_note_manager/same_valid_s4/I0
14.221 | 0.465 | tINS | RR | 2 | R24C90[2][A] | g_sound.u_note_manager/same_valid_s4/F
14.365 | 0.144 | tNET | RR | 1 | R25C90[3][B] | g_sound.u_note_manager/same_valid_s0/I3
14.738 | 0.373 | tINS | RR | 4 | R25C90[3][B] | g_sound.u_note_manager/same_valid_s0/F
17.560 | 2.822 | tNET | RR | 1 | R61C56[0][B] | g_sound.u_note_manager/n24370_s10/I2
18.024 | 0.465 | tINS | RR | 4 | R61C56[0][B] | g_sound.u_note_manager/n24370_s10/F
18.891 | 0.866 | tNET | RR | 1 | R61C51[2][A] | g_sound.u_note_manager/n26753_s12/I1
19.102 | 0.211 | tINS | RF | 34 | R61C51[2][A] | g_sound.u_note_manager/n26753_s12/F
19.533 | 0.431 | tNET | FF | 1 | R60C52[3][B] | g_sound.u_note_manager/n26757_s11/I3
19.907 | 0.373 | tINS | FR | 1 | R60C52[3][B] | g_sound.u_note_manager/n26757_s11/F
19.907 | 0.000 | tNET | RR | 1 | R60C52[3][B] | g_sound.u_note_manager/scan_sel_27_s0/D

Data Required Path:

AT | DELAY | TYPE | RF | FANOUT | LOC | NODE
17.800 | 17.800 | | | | | active clock edge time
17.800 | 0.000 | | | | | clk_sys
17.800 | 0.000 | tCL | RR | 1 | IOB117[B] | clk_ibuf/I
19.088 | 1.288 | tINS | RR | 17271 | IOB117[B] | clk_ibuf/O
21.942 | 2.854 | tNET | RR | 1 | R60C52[3][B] | g_sound.u_note_manager/scan_sel_27_s0/CLK
21.885 | -0.057 | tSu | | 1 | R60C52[3][B] | g_sound.u_note_manager/scan_sel_27_s0

Path Statistics:

Clock Skew | -0.008
Setup Relationship | 17.800
Logic Level | 10
Arrival Clock Path Delay | cell: 1.288, 31.042%; route: 2.862, 68.958%
Arrival Data Path Delay | cell: 3.323, 21.092%; route: 10.624, 67.427%; tC2Q: 1.809, 11.481%
Required Clock Path Delay | cell: 1.288, 31.105%; route: 2.854, 68.895%

### Path25

Path Summary:

Slack | 1.987
Data Arrival Time | 16.701
Data Required Time | 18.688
From | g_sound.u_adc_farm/u_scan0/sample_channel_0_s0
To | g_sound.u_calib1/n909_s
Launch Clk | clk_sys:[R]
Latch Clk | clk_sys:[R]

Data Arrival Path:

AT | DELAY | TYPE | RF | FANOUT | LOC | NODE
0.000 | 0.000 | | | | | active clock edge time
0.000 | 0.000 | | | | | clk_sys
0.000 | 0.000 | tCL | RR | 1 | IOB117[B] | clk_ibuf/I
1.288 | 1.288 | tINS | RR | 17271 | IOB117[B] | clk_ibuf/O
4.150 | 2.862 | tNET | RR | 1 | R71C128[1][A] | g_sound.u_adc_farm/u_scan0/sample_channel_0_s0/CLK
4.481 | 0.331 | tC2Q | RF | 146 | R71C128[1][A] | g_sound.u_adc_farm/u_scan0/sample_channel_0_s0/Q
8.449 | 3.968 | tNET | FF | 1 | R61C102[2][B] | g_sound.u_calib1/n64_s19/I2
8.864 | 0.415 | tINS | FR | 1 | R61C102[2][B] | g_sound.u_calib1/n64_s19/F
8.864 | 0.000 | tNET | RR | 1 | R61C102[2][A] | g_sound.u_calib1/n64_s15/I1
8.987 | 0.123 | tINS | RR | 1 | R61C102[2][A] | g_sound.u_calib1/n64_s15/O
8.987 | 0.000 | tNET | RR | 1 | R61C102[2][B] | g_sound.u_calib1/n64_s13/I1
9.064 | 0.078 | tINS | RR | 1 | R61C102[2][B] | g_sound.u_calib1/n64_s13/O
9.725 | 0.660 | tNET | RR | 1 | R70C103[0][B] | g_sound.u_calib1/dclamp_9_s7/I3
10.189 | 0.465 | tINS | RR | 1 | R70C103[0][B] | g_sound.u_calib1/dclamp_9_s7/F
10.534 | 0.344 | tNET | RR | 1 | R68C102[3][B] | g_sound.u_calib1/dclamp_9_s4/I3
11.003 | 0.469 | tINS | RR | 16 | R68C102[3][B] | g_sound.u_calib1/dclamp_9_s4/F
11.651 | 0.648 | tNET | RR | 1 | R72C103[1][A] | g_sound.u_calib1/dclamp_8_s17/I3
11.887 | 0.236 | tINS | RR | 1 | R72C103[1][A] | g_sound.u_calib1/dclamp_8_s17/F
12.029 | 0.142 | tNET | RR | 1 | R72C104[3][B] | g_sound.u_calib1/dclamp_8_s20/I1
12.402 | 0.373 | tINS | RR | 1 | R72C104[3][B] | g_sound.u_calib1/dclamp_8_s20/F
12.526 | 0.124 | tNET | RR | 1 | R72C104[1][B] | g_sound.u_calib1/dclamp_8_s15/I2
12.762 | 0.236 | tINS | RR | 1 | R72C104[1][B] | g_sound.u_calib1/dclamp_8_s15/F
12.935 | 0.173 | tNET | RR | 1 | R72C106[1][B] | g_sound.u_calib1/dclamp_8_s13/I3
13.400 | 0.465 | tINS | RR | 2 | R72C106[1][B] | g_sound.u_calib1/dclamp_8_s13/F
13.544 | 0.144 | tNET | RR | 1 | R72C105[2][A] | g_sound.u_calib1/dclamp_8_s12/I3
13.780 | 0.236 | tINS | RR | 1 | R72C105[2][A] | g_sound.u_calib1/dclamp_8_s12/F
13.783 | 0.002 | tNET | RR | 1 | R72C105[1][A] | g_sound.u_calib1/dclamp_8_s7/I3
14.198 | 0.415 | tINS | RR | 2 | R72C105[1][A] | g_sound.u_calib1/dclamp_8_s7/F
14.342 | 0.144 | tNET | RR | 1 | R71C105[0][A] | g_sound.u_calib1/dclamp_8_s3/I2
14.757 | 0.415 | tINS | RR | 9 | R71C105[0][A] | g_sound.u_calib1/dclamp_8_s3/F
15.433 | 0.676 | tNET | RR | 1 | R71C101[3][A] | g_sound.u_calib1/dclamp_3_s0/I0
15.902 | 0.469 | tINS | RR | 1 | R71C101[3][A] | g_sound.u_calib1/dclamp_3_s0/F
16.701 | 0.799 | tNET | RR | 1 | DSP_R65[33] | g_sound.u_calib1/n909_s/A[3]

Data Required Path:

AT | DELAY | TYPE | RF | FANOUT | LOC | NODE
17.800 | 17.800 | | | | | active clock edge time
17.800 | 0.000 | | | | | clk_sys
17.800 | 0.000 | tCL | RR | 1 | IOB117[B] | clk_ibuf/I
19.088 | 1.288 | tINS | RR | 17271 | IOB117[B] | clk_ibuf/O
21.942 | 2.854 | tNET | RR | 1 | DSP_R65[33] | g_sound.u_calib1/n909_s/CLK[0]
18.688 | -3.254 | tSu | | 1 | DSP_R65[33] | g_sound.u_calib1/n909_s

Path Statistics:

Clock Skew | -0.008
Setup Relationship | 17.800
Logic Level | 12
Arrival Clock Path Delay | cell: 1.288, 31.042%; route: 2.862, 68.958%
Arrival Data Path Delay | cell: 4.395, 35.022%; route: 7.824, 62.343%; tC2Q: 0.331, 2.635%
Required Clock Path Delay | cell: 1.288, 31.105%; route: 2.854, 68.895%

### Hold Analysis Report

#### Report Command:report_timing -hold -max_paths 25 -max_common_paths 1

### Path1

Path Summary:

Slack | 0.125
Data Arrival Time | 3.189
Data Required Time | 3.064
From | u_rst_sync/sync_chain_1_s0
To | u_hdmi/rstn_ser_0_s0
Launch Clk | clk_sys:[R]
Latch Clk | serial_clk:[R]

Data Arrival Path:

AT | DELAY | TYPE | RF | FANOUT | LOC | NODE
0.000 | 0.000 | | | | | active clock edge time
0.000 | 0.000 | | | | | clk_sys
0.000 | 0.000 | tCL | RR | 1 | IOB117[B] | clk_ibuf/I
0.952 | 0.952 | tINS | RR | 17271 | IOB117[B] | clk_ibuf/O
2.190 | 1.237 | tNET | RR | 1 | R73C54[0][A] | u_rst_sync/sync_chain_1_s0/CLK
2.319 | 0.130 | tC2Q | RR | 11902 | R73C54[0][A] | u_rst_sync/sync_chain_1_s0/Q
3.189 | 0.869 | tNET | RR | 1 | R34C146[1][A] | u_hdmi/rstn_ser_0_s0/RESET

Data Required Path:

AT | DELAY | TYPE | RF | FANOUT | LOC | NODE
0.000 | 0.000 | | | | | active clock edge time
0.000 | 0.000 | | | | | serial_clk
2.186 | 2.186 | tCL | RR | 7 | PLL_R[1] | u_hdmi/u_clk/u_pll/CLKOUT0
3.113 | 0.927 | tNET | RR | 1 | R34C146[1][A] | u_hdmi/rstn_ser_0_s0/CLK
3.148 | 0.035 | tUnc
3.064 | -0.085 | tHld | | 1 | R34C146[1][A] | u_hdmi/rstn_ser_0_s0

Path Statistics:

Clock Skew | 0.923
Hold Relationship | 0.000
Logic Level | 1
Arrival Clock Path Delay | cell: 0.952, 43.487%; route: 1.237, 56.513%
Arrival Data Path Delay | cell: 0.000, 0.000%; route: 0.869, 87.027%; tC2Q: 0.130, 12.973%
Required Clock Path Delay | cell: 0.000, 0.000%; route: 0.927, 100.000%

### Path2

Path Summary:

Slack | 0.130
Data Arrival Time | 3.003
Data Required Time | 2.874
From | u_hdmi/u_blue/symbol_6_s0
To | u_hdmi/u_serializer/lanes[0].u_oser
Launch Clk | pixel_clk:[R]
Latch Clk | pixel_clk:[R]

Data Arrival Path:

AT | DELAY | TYPE | RF | FANOUT | LOC | NODE
0.000 | 0.000 | | | | | active clock edge time
0.000 | 0.000 | | | | | pixel_clk
2.186 | 2.186 | tCL | RR | 336 | PLL_R[1] | u_hdmi/u_clk/u_pll/CLKOUT1
2.788 | 0.602 | tNET | RR | 1 | R26C146[1][B] | u_hdmi/u_blue/symbol_6_s0/CLK
2.918 | 0.130 | tC2Q | RR | 2 | R26C146[1][B] | u_hdmi/u_blue/symbol_6_s0/Q
3.003 | 0.086 | tNET | RR | 1 | IOR26[A] | u_hdmi/u_serializer/lanes[0].u_oser/D6

Data Required Path:

AT | DELAY | TYPE | RF | FANOUT | LOC | NODE
0.000 | 0.000 | | | | | active clock edge time
0.000 | 0.000 | | | | | pixel_clk
2.186 | 2.186 | tCL | RR | 336 | PLL_R[1] | u_hdmi/u_clk/u_pll/CLKOUT1
2.788 | 0.602 | tNET | RR | 1 | IOR26[A] | u_hdmi/u_serializer/lanes[0].u_oser/PCLK
2.874 | 0.085 | tHld | | 1 | IOR26[A] | u_hdmi/u_serializer/lanes[0].u_oser

Path Statistics:

Clock Skew | 0.000
Hold Relationship | 0.000
Logic Level | 1
Arrival Clock Path Delay | cell: 0.000, 0.000%; route: 0.602, 100.000%
Arrival Data Path Delay | cell: 0.000, 0.000%; route: 0.086, 39.749%; tC2Q: 0.130, 60.251%
Required Clock Path Delay | cell: 0.000, 0.000%; route: 0.602, 100.000%

### Path3

Path Summary:

Slack | 0.130
Data Arrival Time | 3.003
Data Required Time | 2.874
From | u_hdmi/u_blue/symbol_7_s0
To | u_hdmi/u_serializer/lanes[0].u_oser
Launch Clk | pixel_clk:[R]
Latch Clk | pixel_clk:[R]

Data Arrival Path:

AT | DELAY | TYPE | RF | FANOUT | LOC | NODE
0.000 | 0.000 | | | | | active clock edge time
0.000 | 0.000 | | | | | pixel_clk
2.186 | 2.186 | tCL | RR | 336 | PLL_R[1] | u_hdmi/u_clk/u_pll/CLKOUT1
2.788 | 0.602 | tNET | RR | 1 | R26C146[2][A] | u_hdmi/u_blue/symbol_7_s0/CLK
2.918 | 0.130 | tC2Q | RR | 4 | R26C146[2][A] | u_hdmi/u_blue/symbol_7_s0/Q
3.003 | 0.086 | tNET | RR | 1 | IOR26[A] | u_hdmi/u_serializer/lanes[0].u_oser/D0

Data Required Path:

AT | DELAY | TYPE | RF | FANOUT | LOC | NODE
0.000 | 0.000 | | | | | active clock edge time
0.000 | 0.000 | | | | | pixel_clk
2.186 | 2.186 | tCL | RR | 336 | PLL_R[1] | u_hdmi/u_clk/u_pll/CLKOUT1
2.788 | 0.602 | tNET | RR | 1 | IOR26[A] | u_hdmi/u_serializer/lanes[0].u_oser/PCLK
2.874 | 0.085 | tHld | | 1 | IOR26[A] | u_hdmi/u_serializer/lanes[0].u_oser

Path Statistics:

Clock Skew | 0.000
Hold Relationship | 0.000
Logic Level | 1
Arrival Clock Path Delay | cell: 0.000, 0.000%; route: 0.602, 100.000%
Arrival Data Path Delay | cell: 0.000, 0.000%; route: 0.086, 39.749%; tC2Q: 0.130, 60.251%
Required Clock Path Delay | cell: 0.000, 0.000%; route: 0.602, 100.000%

### Path4

Path Summary:

Slack | 0.198
Data Arrival Time | 2.591
Data Required Time | 2.393
From | g_sound.demo_note_inc_25_s0
To | g_sound.u_seq_arb/mem_mem_RAMREG_3_G[35]_s0
Launch Clk | clk_sys:[R]
Latch Clk | clk_sys:[R]

Data Arrival Path:

AT | DELAY | TYPE | RF | FANOUT | LOC | NODE
0.000 | 0.000 | | | | | active clock edge time
0.000 | 0.000 | | | | | clk_sys
0.000 | 0.000 | tCL | RR | 1 | IOB117[B] | clk_ibuf/I
0.952 | 0.952 | tINS | RR | 17271 | IOB117[B] | clk_ibuf/O
2.186 | 1.234 | tNET | RR | 1 | R39C5[1][B] | g_sound.demo_note_inc_25_s0/CLK
2.316 | 0.130 | tC2Q | RR | 55 | R39C5[1][B] | g_sound.demo_note_inc_25_s0/Q
2.453 | 0.138 | tNET | RR | 1 | R35C3[1][A] | g_sound.u_seq_arb/mem_s2603/I0
2.591 | 0.138 | tINS | RF | 1 | R35C3[1][A] | g_sound.u_seq_arb/mem_s2603/F
2.591 | 0.000 | tNET | FF | 1 | R35C3[1][A] | g_sound.u_seq_arb/mem_mem_RAMREG_3_G[35]_s0/D

Data Required Path:

AT | DELAY | TYPE | RF | FANOUT | LOC | NODE
0.000 | 0.000 | | | | | active clock edge time
0.000 | 0.000 | | | | | clk_sys
0.000 | 0.000 | tCL | RR | 1 | IOB117[B] | clk_ibuf/I
0.952 | 0.952 | tINS | RR | 17271 | IOB117[B] | clk_ibuf/O
2.371 | 1.418 | tNET | RR | 1 | R35C3[1][A] | g_sound.u_seq_arb/mem_mem_RAMREG_3_G[35]_s0/CLK
2.393 | 0.022 | tHld | | 1 | R35C3[1][A] | g_sound.u_seq_arb/mem_mem_RAMREG_3_G[35]_s0

Path Statistics:

Clock Skew | 0.185
Hold Relationship | 0.000
Logic Level | 2
Arrival Clock Path Delay | cell: 0.952, 43.558%; route: 1.234, 56.442%
Arrival Data Path Delay | cell: 0.138, 34.000%; route: 0.138, 34.000%; tC2Q: 0.130, 32.000%
Required Clock Path Delay | cell: 0.952, 40.168%; route: 1.418, 59.832%

### Path5

Path Summary:

Slack | 0.201
Data Arrival Time | 3.074
Data Required Time | 2.874
From | u_hdmi/u_blue/symbol_4_s0
To | u_hdmi/u_serializer/lanes[0].u_oser
Launch Clk | pixel_clk:[R]
Latch Clk | pixel_clk:[R]

Data Arrival Path:

AT | DELAY | TYPE | RF | FANOUT | LOC | NODE
0.000 | 0.000 | | | | | active clock edge time
0.000 | 0.000 | | | | | pixel_clk
2.186 | 2.186 | tCL | RR | 336 | PLL_R[1] | u_hdmi/u_clk/u_pll/CLKOUT1
2.788 | 0.602 | tNET | RR | 1 | R26C146[0][B] | u_hdmi/u_blue/symbol_4_s0/CLK
2.918 | 0.130 | tC2Q | RR | 1 | R26C146[0][B] | u_hdmi/u_blue/symbol_4_s0/Q
3.074 | 0.157 | tNET | RR | 1 | IOR26[A] | u_hdmi/u_serializer/lanes[0].u_oser/D4

Data Required Path:

AT | DELAY | TYPE | RF | FANOUT | LOC | NODE
0.000 | 0.000 | | | | | active clock edge time
0.000 | 0.000 | | | | | pixel_clk
2.186 | 2.186 | tCL | RR | 336 | PLL_R[1] | u_hdmi/u_clk/u_pll/CLKOUT1
2.788 | 0.602 | tNET | RR | 1 | IOR26[A] | u_hdmi/u_serializer/lanes[0].u_oser/PCLK
2.874 | 0.085 | tHld | | 1 | IOR26[A] | u_hdmi/u_serializer/lanes[0].u_oser

Path Statistics:

Clock Skew | 0.000
Hold Relationship | 0.000
Logic Level | 1
Arrival Clock Path Delay | cell: 0.000, 0.000%; route: 0.602, 100.000%
Arrival Data Path Delay | cell: 0.000, 0.000%; route: 0.157, 54.717%; tC2Q: 0.130, 45.283%
Required Clock Path Delay | cell: 0.000, 0.000%; route: 0.602, 100.000%

### Path6

Path Summary:

Slack | 0.202
Data Arrival Time | 2.591
Data Required Time | 2.390
From | g_sound.demo_note_inc_25_s0
To | g_sound.u_seq_arb/mem_mem_RAMREG_5_G[35]_s0
Launch Clk | clk_sys:[R]
Latch Clk | clk_sys:[R]

Data Arrival Path:

AT | DELAY | TYPE | RF | FANOUT | LOC | NODE
0.000 | 0.000 | | | | | active clock edge time
0.000 | 0.000 | | | | | clk_sys
0.000 | 0.000 | tCL | RR | 1 | IOB117[B] | clk_ibuf/I
0.952 | 0.952 | tINS | RR | 17271 | IOB117[B] | clk_ibuf/O
2.186 | 1.234 | tNET | RR | 1 | R39C5[1][B] | g_sound.demo_note_inc_25_s0/CLK
2.316 | 0.130 | tC2Q | RR | 55 | R39C5[1][B] | g_sound.demo_note_inc_25_s0/Q
2.453 | 0.138 | tNET | RR | 1 | R35C4[2][A] | g_sound.u_seq_arb/mem_s2659/I0
2.591 | 0.138 | tINS | RF | 1 | R35C4[2][A] | g_sound.u_seq_arb/mem_s2659/F
2.591 | 0.000 | tNET | FF | 1 | R35C4[2][A] | g_sound.u_seq_arb/mem_mem_RAMREG_5_G[35]_s0/D

Data Required Path:

AT | DELAY | TYPE | RF | FANOUT | LOC | NODE
0.000 | 0.000 | | | | | active clock edge time
0.000 | 0.000 | | | | | clk_sys
0.000 | 0.000 | tCL | RR | 1 | IOB117[B] | clk_ibuf/I
0.952 | 0.952 | tINS | RR | 17271 | IOB117[B] | clk_ibuf/O
2.367 | 1.415 | tNET | RR | 1 | R35C4[2][A] | g_sound.u_seq_arb/mem_mem_RAMREG_5_G[35]_s0/CLK
2.390 | 0.022 | tHld | | 1 | R35C4[2][A] | g_sound.u_seq_arb/mem_mem_RAMREG_5_G[35]_s0

Path Statistics:

Clock Skew | 0.181
Hold Relationship | 0.000
Logic Level | 2
Arrival Clock Path Delay | cell: 0.952, 43.558%; route: 1.234, 56.442%
Arrival Data Path Delay | cell: 0.138, 34.000%; route: 0.138, 34.000%; tC2Q: 0.130, 32.000%
Required Clock Path Delay | cell: 0.952, 40.230%; route: 1.415, 59.770%

### Path7

Path Summary:

Slack | 0.212
Data Arrival Time | 3.074
Data Required Time | 2.863
From | u_hdmi/u_blue/symbol_3_s0
To | u_hdmi/u_serializer/lanes[0].u_oser
Launch Clk | pixel_clk:[R]
Latch Clk | pixel_clk:[R]

Data Arrival Path:

AT | DELAY | TYPE | RF | FANOUT | LOC | NODE
0.000 | 0.000 | | | | | active clock edge time
0.000 | 0.000 | | | | | pixel_clk
2.186 | 2.186 | tCL | RR | 336 | PLL_R[1] | u_hdmi/u_clk/u_pll/CLKOUT1
2.788 | 0.602 | tNET | RR | 1 | R26C146[0][A] | u_hdmi/u_blue/symbol_3_s0/CLK
2.918 | 0.130 | tC2Q | RR | 1 | R26C146[0][A] | u_hdmi/u_blue/symbol_3_s0/Q
3.074 | 0.157 | tNET | RR | 1 | IOR26[A] | u_hdmi/u_serializer/lanes[0].u_oser/D3

Data Required Path:

AT | DELAY | TYPE | RF | FANOUT | LOC | NODE
0.000 | 0.000 | | | | | active clock edge time
0.000 | 0.000 | | | | | pixel_clk
2.186 | 2.186 | tCL | RR | 336 | PLL_R[1] | u_hdmi/u_clk/u_pll/CLKOUT1
2.788 | 0.602 | tNET | RR | 1 | IOR26[A] | u_hdmi/u_serializer/lanes[0].u_oser/PCLK
2.863 | 0.075 | tHld | | 1 | IOR26[A] | u_hdmi/u_serializer/lanes[0].u_oser

Path Statistics:

Clock Skew | 0.000
Hold Relationship | 0.000
Logic Level | 1
Arrival Clock Path Delay | cell: 0.000, 0.000%; route: 0.602, 100.000%
Arrival Data Path Delay | cell: 0.000, 0.000%; route: 0.157, 54.717%; tC2Q: 0.130, 45.283%
Required Clock Path Delay | cell: 0.000, 0.000%; route: 0.602, 100.000%

### Path8

Path Summary:

Slack | 0.216
Data Arrival Time | 3.090
Data Required Time | 2.874
From | u_hdmi/u_blue/symbol_6_s0
To | u_hdmi/u_serializer/lanes[0].u_oser
Launch Clk | pixel_clk:[R]
Latch Clk | pixel_clk:[R]

Data Arrival Path:

AT | DELAY | TYPE | RF | FANOUT | LOC | NODE
0.000 | 0.000 | | | | | active clock edge time
0.000 | 0.000 | | | | | pixel_clk
2.186 | 2.186 | tCL | RR | 336 | PLL_R[1] | u_hdmi/u_clk/u_pll/CLKOUT1
2.788 | 0.602 | tNET | RR | 1 | R26C146[1][B] | u_hdmi/u_blue/symbol_6_s0/CLK
2.918 | 0.130 | tC2Q | RR | 2 | R26C146[1][B] | u_hdmi/u_blue/symbol_6_s0/Q
3.090 | 0.172 | tNET | RR | 1 | IOR26[A] | u_hdmi/u_serializer/lanes[0].u_oser/D2

Data Required Path:

AT | DELAY | TYPE | RF | FANOUT | LOC | NODE
0.000 | 0.000 | | | | | active clock edge time
0.000 | 0.000 | | | | | pixel_clk
2.186 | 2.186 | tCL | RR | 336 | PLL_R[1] | u_hdmi/u_clk/u_pll/CLKOUT1
2.788 | 0.602 | tNET | RR | 1 | IOR26[A] | u_hdmi/u_serializer/lanes[0].u_oser/PCLK
2.874 | 0.085 | tHld | | 1 | IOR26[A] | u_hdmi/u_serializer/lanes[0].u_oser

Path Statistics:

Clock Skew | 0.000
Hold Relationship | 0.000
Logic Level | 1
Arrival Clock Path Delay | cell: 0.000, 0.000%; route: 0.602, 100.000%
Arrival Data Path Delay | cell: 0.000, 0.000%; route: 0.172, 57.015%; tC2Q: 0.130, 42.985%
Required Clock Path Delay | cell: 0.000, 0.000%; route: 0.602, 100.000%

### Path9

Path Summary:

Slack | 0.225
Data Arrival Time | 3.088
Data Required Time | 2.863
From | u_hdmi/u_blue/symbol_9_s0
To | u_hdmi/u_serializer/lanes[0].u_oser
Launch Clk | pixel_clk:[R]
Latch Clk | pixel_clk:[R]

Data Arrival Path:

AT | DELAY | TYPE | RF | FANOUT | LOC | NODE
0.000 | 0.000 | | | | | active clock edge time
0.000 | 0.000 | | | | | pixel_clk
2.186 | 2.186 | tCL | RR | 336 | PLL_R[1] | u_hdmi/u_clk/u_pll/CLKOUT1
2.788 | 0.602 | tNET | RR | 1 | R26C146[1][A] | u_hdmi/u_blue/symbol_9_s0/CLK
2.918 | 0.130 | tC2Q | RR | 1 | R26C146[1][A] | u_hdmi/u_blue/symbol_9_s0/Q
3.088 | 0.170 | tNET | RR | 1 | IOR26[A] | u_hdmi/u_serializer/lanes[0].u_oser/D9

Data Required Path:

AT | DELAY | TYPE | RF | FANOUT | LOC | NODE
0.000 | 0.000 | | | | | active clock edge time
0.000 | 0.000 | | | | | pixel_clk
2.186 | 2.186 | tCL | RR | 336 | PLL_R[1] | u_hdmi/u_clk/u_pll/CLKOUT1
2.788 | 0.602 | tNET | RR | 1 | IOR26[A] | u_hdmi/u_serializer/lanes[0].u_oser/PCLK
2.863 | 0.075 | tHld | | 1 | IOR26[A] | u_hdmi/u_serializer/lanes[0].u_oser

Path Statistics:

Clock Skew | 0.000
Hold Relationship | 0.000
Logic Level | 1
Arrival Clock Path Delay | cell: 0.000, 0.000%; route: 0.602, 100.000%
Arrival Data Path Delay | cell: 0.000, 0.000%; route: 0.170, 56.757%; tC2Q: 0.130, 43.243%
Required Clock Path Delay | cell: 0.000, 0.000%; route: 0.602, 100.000%

### Path10

Path Summary:

Slack | 0.247
Data Arrival Time | 2.637
Data Required Time | 2.390
From | u_led_indicator/beat_t_9_s1
To | u_led_indicator/beat_t_9_s1
Launch Clk | clk_sys:[R]
Latch Clk | clk_sys:[R]

Data Arrival Path:

AT | DELAY | TYPE | RF | FANOUT | LOC | NODE
0.000 | 0.000 | | | | | active clock edge time
0.000 | 0.000 | | | | | clk_sys
0.000 | 0.000 | tCL | RR | 1 | IOB117[B] | clk_ibuf/I
0.952 | 0.952 | tINS | RR | 17271 | IOB117[B] | clk_ibuf/O
2.367 | 1.415 | tNET | RR | 1 | R30C24[0][A] | u_led_indicator/beat_t_9_s1/CLK
2.494 | 0.127 | tC2Q | RF | 2 | R30C24[0][A] | u_led_indicator/beat_t_9_s1/Q
2.499 | 0.005 | tNET | FF | 1 | R30C24[0][A] | u_led_indicator/n117_s1/I1
2.637 | 0.138 | tINS | FF | 1 | R30C24[0][A] | u_led_indicator/n117_s1/F
2.637 | 0.000 | tNET | FF | 1 | R30C24[0][A] | u_led_indicator/beat_t_9_s1/D

Data Required Path:

AT | DELAY | TYPE | RF | FANOUT | LOC | NODE
0.000 | 0.000 | | | | | active clock edge time
0.000 | 0.000 | | | | | clk_sys
0.000 | 0.000 | tCL | RR | 1 | IOB117[B] | clk_ibuf/I
0.952 | 0.952 | tINS | RR | 17271 | IOB117[B] | clk_ibuf/O
2.367 | 1.415 | tNET | RR | 1 | R30C24[0][A] | u_led_indicator/beat_t_9_s1/CLK
2.390 | 0.022 | tHld | | 1 | R30C24[0][A] | u_led_indicator/beat_t_9_s1

Path Statistics:

Clock Skew | 0.000
Hold Relationship | 0.000
Logic Level | 2
Arrival Clock Path Delay | cell: 0.952, 40.230%; route: 1.415, 59.770%
Arrival Data Path Delay | cell: 0.138, 51.000%; route: 0.005, 2.000%; tC2Q: 0.127, 47.000%
Required Clock Path Delay | cell: 0.952, 40.230%; route: 1.415, 59.770%

### Path11

Path Summary:

Slack | 0.247
Data Arrival Time | 2.456
Data Required Time | 2.209
From | u_ws2812/led_i_0_s1
To | u_ws2812/led_i_0_s1
Launch Clk | clk_sys:[R]
Latch Clk | clk_sys:[R]

Data Arrival Path:

AT | DELAY | TYPE | RF | FANOUT | LOC | NODE
0.000 | 0.000 | | | | | active clock edge time
0.000 | 0.000 | | | | | clk_sys
0.000 | 0.000 | tCL | RR | 1 | IOB117[B] | clk_ibuf/I
0.952 | 0.952 | tINS | RR | 17271 | IOB117[B] | clk_ibuf/O
2.186 | 1.234 | tNET | RR | 1 | R42C49[1][A] | u_ws2812/led_i_0_s1/CLK
2.313 | 0.127 | tC2Q | RF | 7 | R42C49[1][A] | u_ws2812/led_i_0_s1/Q
2.318 | 0.005 | tNET | FF | 1 | R42C49[1][A] | u_ws2812/n547_s7/I0
2.456 | 0.138 | tINS | FF | 1 | R42C49[1][A] | u_ws2812/n547_s7/F
2.456 | 0.000 | tNET | FF | 1 | R42C49[1][A] | u_ws2812/led_i_0_s1/D

Data Required Path:

AT | DELAY | TYPE | RF | FANOUT | LOC | NODE
0.000 | 0.000 | | | | | active clock edge time
0.000 | 0.000 | | | | | clk_sys
0.000 | 0.000 | tCL | RR | 1 | IOB117[B] | clk_ibuf/I
0.952 | 0.952 | tINS | RR | 17271 | IOB117[B] | clk_ibuf/O
2.186 | 1.234 | tNET | RR | 1 | R42C49[1][A] | u_ws2812/led_i_0_s1/CLK
2.209 | 0.022 | tHld | | 1 | R42C49[1][A] | u_ws2812/led_i_0_s1

Path Statistics:

Clock Skew | 0.000
Hold Relationship | 0.000
Logic Level | 2
Arrival Clock Path Delay | cell: 0.952, 43.558%; route: 1.234, 56.442%
Arrival Data Path Delay | cell: 0.138, 51.000%; route: 0.005, 2.000%; tC2Q: 0.127, 47.000%
Required Clock Path Delay | cell: 0.952, 43.558%; route: 1.234, 56.442%

### Path12

Path Summary:

Slack | 0.247
Data Arrival Time | 2.460
Data Required Time | 2.212
From | u_ws2812/led_i_1_s1
To | u_ws2812/led_i_1_s1
Launch Clk | clk_sys:[R]
Latch Clk | clk_sys:[R]

Data Arrival Path:

AT | DELAY | TYPE | RF | FANOUT | LOC | NODE
0.000 | 0.000 | | | | | active clock edge time
0.000 | 0.000 | | | | | clk_sys
0.000 | 0.000 | tCL | RR | 1 | IOB117[B] | clk_ibuf/I
0.952 | 0.952 | tINS | RR | 17271 | IOB117[B] | clk_ibuf/O
2.190 | 1.237 | tNET | RR | 1 | R43C48[0][A] | u_ws2812/led_i_1_s1/CLK
2.317 | 0.127 | tC2Q | RF | 5 | R43C48[0][A] | u_ws2812/led_i_1_s1/Q
2.322 | 0.005 | tNET | FF | 1 | R43C48[0][A] | u_ws2812/n546_s6/I1
2.460 | 0.138 | tINS | FF | 1 | R43C48[0][A] | u_ws2812/n546_s6/F
2.460 | 0.000 | tNET | FF | 1 | R43C48[0][A] | u_ws2812/led_i_1_s1/D

Data Required Path:

AT | DELAY | TYPE | RF | FANOUT | LOC | NODE
0.000 | 0.000 | | | | | active clock edge time
0.000 | 0.000 | | | | | clk_sys
0.000 | 0.000 | tCL | RR | 1 | IOB117[B] | clk_ibuf/I
0.952 | 0.952 | tINS | RR | 17271 | IOB117[B] | clk_ibuf/O
2.190 | 1.237 | tNET | RR | 1 | R43C48[0][A] | u_ws2812/led_i_1_s1/CLK
2.212 | 0.022 | tHld | | 1 | R43C48[0][A] | u_ws2812/led_i_1_s1

Path Statistics:

Clock Skew | 0.000
Hold Relationship | 0.000
Logic Level | 2
Arrival Clock Path Delay | cell: 0.952, 43.487%; route: 1.237, 56.513%
Arrival Data Path Delay | cell: 0.138, 51.000%; route: 0.005, 2.000%; tC2Q: 0.127, 47.000%
Required Clock Path Delay | cell: 0.952, 43.487%; route: 1.237, 56.513%

### Path13

Path Summary:

Slack | 0.247
Data Arrival Time | 2.460
Data Required Time | 2.212
From | u_i2s_tx_ext/ch_s0
To | u_i2s_tx_ext/ch_s0
Launch Clk | clk_sys:[R]
Latch Clk | clk_sys:[R]

Data Arrival Path:

AT | DELAY | TYPE | RF | FANOUT | LOC | NODE
0.000 | 0.000 | | | | | active clock edge time
0.000 | 0.000 | | | | | clk_sys
0.000 | 0.000 | tCL | RR | 1 | IOB117[B] | clk_ibuf/I
0.952 | 0.952 | tINS | RR | 17271 | IOB117[B] | clk_ibuf/O
2.190 | 1.237 | tNET | RR | 1 | R57C131[0][A] | u_i2s_tx_ext/ch_s0/CLK
2.317 | 0.127 | tC2Q | RF | 2 | R57C131[0][A] | u_i2s_tx_ext/ch_s0/Q
2.322 | 0.005 | tNET | FF | 1 | R57C131[0][A] | u_i2s_tx_ext/n121_s2/I0
2.460 | 0.138 | tINS | FF | 1 | R57C131[0][A] | u_i2s_tx_ext/n121_s2/F
2.460 | 0.000 | tNET | FF | 1 | R57C131[0][A] | u_i2s_tx_ext/ch_s0/D

Data Required Path:

AT | DELAY | TYPE | RF | FANOUT | LOC | NODE
0.000 | 0.000 | | | | | active clock edge time
0.000 | 0.000 | | | | | clk_sys
0.000 | 0.000 | tCL | RR | 1 | IOB117[B] | clk_ibuf/I
0.952 | 0.952 | tINS | RR | 17271 | IOB117[B] | clk_ibuf/O
2.190 | 1.237 | tNET | RR | 1 | R57C131[0][A] | u_i2s_tx_ext/ch_s0/CLK
2.212 | 0.022 | tHld | | 1 | R57C131[0][A] | u_i2s_tx_ext/ch_s0

Path Statistics:

Clock Skew | 0.000
Hold Relationship | 0.000
Logic Level | 2
Arrival Clock Path Delay | cell: 0.952, 43.487%; route: 1.237, 56.513%
Arrival Data Path Delay | cell: 0.138, 51.000%; route: 0.005, 2.000%; tC2Q: 0.127, 47.000%
Required Clock Path Delay | cell: 0.952, 43.487%; route: 1.237, 56.513%

### Path14

Path Summary:

Slack | 0.247
Data Arrival Time | 2.456
Data Required Time | 2.209
From | u_i2s_tx/ch_s0
To | u_i2s_tx/ch_s0
Launch Clk | clk_sys:[R]
Latch Clk | clk_sys:[R]

Data Arrival Path:

AT | DELAY | TYPE | RF | FANOUT | LOC | NODE
0.000 | 0.000 | | | | | active clock edge time
0.000 | 0.000 | | | | | clk_sys
0.000 | 0.000 | tCL | RR | 1 | IOB117[B] | clk_ibuf/I
0.952 | 0.952 | tINS | RR | 17271 | IOB117[B] | clk_ibuf/O
2.186 | 1.234 | tNET | RR | 1 | R58C130[1][A] | u_i2s_tx/ch_s0/CLK
2.313 | 0.127 | tC2Q | RF | 2 | R58C130[1][A] | u_i2s_tx/ch_s0/Q
2.318 | 0.005 | tNET | FF | 1 | R58C130[1][A] | u_i2s_tx/n156_s2/I0
2.456 | 0.138 | tINS | FF | 1 | R58C130[1][A] | u_i2s_tx/n156_s2/F
2.456 | 0.000 | tNET | FF | 1 | R58C130[1][A] | u_i2s_tx/ch_s0/D

Data Required Path:

AT | DELAY | TYPE | RF | FANOUT | LOC | NODE
0.000 | 0.000 | | | | | active clock edge time
0.000 | 0.000 | | | | | clk_sys
0.000 | 0.000 | tCL | RR | 1 | IOB117[B] | clk_ibuf/I
0.952 | 0.952 | tINS | RR | 17271 | IOB117[B] | clk_ibuf/O
2.186 | 1.234 | tNET | RR | 1 | R58C130[1][A] | u_i2s_tx/ch_s0/CLK
2.209 | 0.022 | tHld | | 1 | R58C130[1][A] | u_i2s_tx/ch_s0

Path Statistics:

Clock Skew | 0.000
Hold Relationship | 0.000
Logic Level | 2
Arrival Clock Path Delay | cell: 0.952, 43.558%; route: 1.234, 56.442%
Arrival Data Path Delay | cell: 0.138, 51.000%; route: 0.005, 2.000%; tC2Q: 0.127, 47.000%
Required Clock Path Delay | cell: 0.952, 43.558%; route: 1.234, 56.442%

### Path15

Path Summary:

Slack | 0.247
Data Arrival Time | 2.456
Data Required Time | 2.209
From | u_i2s_tx/bit_cnt_3_s0
To | u_i2s_tx/bit_cnt_3_s0
Launch Clk | clk_sys:[R]
Latch Clk | clk_sys:[R]

Data Arrival Path:

AT | DELAY | TYPE | RF | FANOUT | LOC | NODE
0.000 | 0.000 | | | | | active clock edge time
0.000 | 0.000 | | | | | clk_sys
0.000 | 0.000 | tCL | RR | 1 | IOB117[B] | clk_ibuf/I
0.952 | 0.952 | tINS | RR | 17271 | IOB117[B] | clk_ibuf/O
2.186 | 1.234 | tNET | RR | 1 | R58C130[0][A] | u_i2s_tx/bit_cnt_3_s0/CLK
2.313 | 0.127 | tC2Q | RF | 4 | R58C130[0][A] | u_i2s_tx/bit_cnt_3_s0/Q
2.318 | 0.005 | tNET | FF | 1 | R58C130[0][A] | u_i2s_tx/n55_s2/I3
2.456 | 0.138 | tINS | FF | 1 | R58C130[0][A] | u_i2s_tx/n55_s2/F
2.456 | 0.000 | tNET | FF | 1 | R58C130[0][A] | u_i2s_tx/bit_cnt_3_s0/D

Data Required Path:

AT | DELAY | TYPE | RF | FANOUT | LOC | NODE
0.000 | 0.000 | | | | | active clock edge time
0.000 | 0.000 | | | | | clk_sys
0.000 | 0.000 | tCL | RR | 1 | IOB117[B] | clk_ibuf/I
0.952 | 0.952 | tINS | RR | 17271 | IOB117[B] | clk_ibuf/O
2.186 | 1.234 | tNET | RR | 1 | R58C130[0][A] | u_i2s_tx/bit_cnt_3_s0/CLK
2.209 | 0.022 | tHld | | 1 | R58C130[0][A] | u_i2s_tx/bit_cnt_3_s0

Path Statistics:

Clock Skew | 0.000
Hold Relationship | 0.000
Logic Level | 2
Arrival Clock Path Delay | cell: 0.952, 43.558%; route: 1.234, 56.442%
Arrival Data Path Delay | cell: 0.138, 51.000%; route: 0.005, 2.000%; tC2Q: 0.127, 47.000%
Required Clock Path Delay | cell: 0.952, 43.558%; route: 1.234, 56.442%

### Path16

Path Summary:

Slack | 0.247
Data Arrival Time | 2.460
Data Required Time | 2.212
From | g_sound.u_tdm_render_mixer/cnt_0_s2
To | g_sound.u_tdm_render_mixer/cnt_0_s2
Launch Clk | clk_sys:[R]
Latch Clk | clk_sys:[R]

Data Arrival Path:

AT | DELAY | TYPE | RF | FANOUT | LOC | NODE
0.000 | 0.000 | | | | | active clock edge time
0.000 | 0.000 | | | | | clk_sys
0.000 | 0.000 | tCL | RR | 1 | IOB117[B] | clk_ibuf/I
0.952 | 0.952 | tINS | RR | 17271 | IOB117[B] | clk_ibuf/O
2.190 | 1.237 | tNET | RR | 1 | R55C107[0][A] | g_sound.u_tdm_render_mixer/cnt_0_s2/CLK
2.317 | 0.127 | tC2Q | RF | 36 | R55C107[0][A] | g_sound.u_tdm_render_mixer/cnt_0_s2/Q
2.322 | 0.005 | tNET | FF | 1 | R55C107[0][A] | g_sound.u_tdm_render_mixer/n649_s3/I2
2.460 | 0.138 | tINS | FF | 1 | R55C107[0][A] | g_sound.u_tdm_render_mixer/n649_s3/F
2.460 | 0.000 | tNET | FF | 1 | R55C107[0][A] | g_sound.u_tdm_render_mixer/cnt_0_s2/D

Data Required Path:

AT | DELAY | TYPE | RF | FANOUT | LOC | NODE
0.000 | 0.000 | | | | | active clock edge time
0.000 | 0.000 | | | | | clk_sys
0.000 | 0.000 | tCL | RR | 1 | IOB117[B] | clk_ibuf/I
0.952 | 0.952 | tINS | RR | 17271 | IOB117[B] | clk_ibuf/O
2.190 | 1.237 | tNET | RR | 1 | R55C107[0][A] | g_sound.u_tdm_render_mixer/cnt_0_s2/CLK
2.212 | 0.022 | tHld | | 1 | R55C107[0][A] | g_sound.u_tdm_render_mixer/cnt_0_s2

Path Statistics:

Clock Skew | 0.000
Hold Relationship | 0.000
Logic Level | 2
Arrival Clock Path Delay | cell: 0.952, 43.487%; route: 1.237, 56.513%
Arrival Data Path Delay | cell: 0.138, 51.000%; route: 0.005, 2.000%; tC2Q: 0.127, 47.000%
Required Clock Path Delay | cell: 0.952, 43.487%; route: 1.237, 56.513%

### Path17

Path Summary:

Slack | 0.247
Data Arrival Time | 2.456
Data Required Time | 2.209
From | g_sound.u_perc_env_bank/gen_perc[4].level_r_0_s0
To | g_sound.u_perc_env_bank/gen_perc[4].level_r_0_s0
Launch Clk | clk_sys:[R]
Latch Clk | clk_sys:[R]

Data Arrival Path:

AT | DELAY | TYPE | RF | FANOUT | LOC | NODE
0.000 | 0.000 | | | | | active clock edge time
0.000 | 0.000 | | | | | clk_sys
0.000 | 0.000 | tCL | RR | 1 | IOB117[B] | clk_ibuf/I
0.952 | 0.952 | tINS | RR | 17271 | IOB117[B] | clk_ibuf/O
2.186 | 1.234 | tNET | RR | 1 | R11C94[0][A] | g_sound.u_perc_env_bank/gen_perc[4].level_r_0_s0/CLK
2.313 | 0.127 | tC2Q | RF | 6 | R11C94[0][A] | g_sound.u_perc_env_bank/gen_perc[4].level_r_0_s0/Q
2.318 | 0.005 | tNET | FF | 1 | R11C94[0][A] | g_sound.u_perc_env_bank/n1574_s2/I1
2.456 | 0.138 | tINS | FF | 1 | R11C94[0][A] | g_sound.u_perc_env_bank/n1574_s2/F
2.456 | 0.000 | tNET | FF | 1 | R11C94[0][A] | g_sound.u_perc_env_bank/gen_perc[4].level_r_0_s0/D

Data Required Path:

AT | DELAY | TYPE | RF | FANOUT | LOC | NODE
0.000 | 0.000 | | | | | active clock edge time
0.000 | 0.000 | | | | | clk_sys
0.000 | 0.000 | tCL | RR | 1 | IOB117[B] | clk_ibuf/I
0.952 | 0.952 | tINS | RR | 17271 | IOB117[B] | clk_ibuf/O
2.186 | 1.234 | tNET | RR | 1 | R11C94[0][A] | g_sound.u_perc_env_bank/gen_perc[4].level_r_0_s0/CLK
2.209 | 0.022 | tHld | | 1 | R11C94[0][A] | g_sound.u_perc_env_bank/gen_perc[4].level_r_0_s0

Path Statistics:

Clock Skew | 0.000
Hold Relationship | 0.000
Logic Level | 2
Arrival Clock Path Delay | cell: 0.952, 43.558%; route: 1.234, 56.442%
Arrival Data Path Delay | cell: 0.138, 51.000%; route: 0.005, 2.000%; tC2Q: 0.127, 47.000%
Required Clock Path Delay | cell: 0.952, 43.558%; route: 1.234, 56.442%

### Path18

Path Summary:

Slack | 0.247
Data Arrival Time | 2.460
Data Required Time | 2.212
From | g_sound.u_perc_env_bank/gen_perc[4].level_r_5_s0
To | g_sound.u_perc_env_bank/gen_perc[4].level_r_5_s0
Launch Clk | clk_sys:[R]
Latch Clk | clk_sys:[R]

Data Arrival Path:

AT | DELAY | TYPE | RF | FANOUT | LOC | NODE
0.000 | 0.000 | | | | | active clock edge time
0.000 | 0.000 | | | | | clk_sys
0.000 | 0.000 | tCL | RR | 1 | IOB117[B] | clk_ibuf/I
0.952 | 0.952 | tINS | RR | 17271 | IOB117[B] | clk_ibuf/O
2.190 | 1.237 | tNET | RR | 1 | R11C95[1][A] | g_sound.u_perc_env_bank/gen_perc[4].level_r_5_s0/CLK
2.317 | 0.127 | tC2Q | RF | 5 | R11C95[1][A] | g_sound.u_perc_env_bank/gen_perc[4].level_r_5_s0/Q
2.322 | 0.005 | tNET | FF | 1 | R11C95[1][A] | g_sound.u_perc_env_bank/n1569_s2/I3
2.460 | 0.138 | tINS | FF | 1 | R11C95[1][A] | g_sound.u_perc_env_bank/n1569_s2/F
2.460 | 0.000 | tNET | FF | 1 | R11C95[1][A] | g_sound.u_perc_env_bank/gen_perc[4].level_r_5_s0/D

Data Required Path:

AT | DELAY | TYPE | RF | FANOUT | LOC | NODE
0.000 | 0.000 | | | | | active clock edge time
0.000 | 0.000 | | | | | clk_sys
0.000 | 0.000 | tCL | RR | 1 | IOB117[B] | clk_ibuf/I
0.952 | 0.952 | tINS | RR | 17271 | IOB117[B] | clk_ibuf/O
2.190 | 1.237 | tNET | RR | 1 | R11C95[1][A] | g_sound.u_perc_env_bank/gen_perc[4].level_r_5_s0/CLK
2.212 | 0.022 | tHld | | 1 | R11C95[1][A] | g_sound.u_perc_env_bank/gen_perc[4].level_r_5_s0

Path Statistics:

Clock Skew | 0.000
Hold Relationship | 0.000
Logic Level | 2
Arrival Clock Path Delay | cell: 0.952, 43.487%; route: 1.237, 56.513%
Arrival Data Path Delay | cell: 0.138, 51.000%; route: 0.005, 2.000%; tC2Q: 0.127, 47.000%
Required Clock Path Delay | cell: 0.952, 43.487%; route: 1.237, 56.513%

### Path19

Path Summary:

Slack | 0.247
Data Arrival Time | 2.456
Data Required Time | 2.209
From | g_sound.u_perc_env_bank/gen_perc[3].level_r_7_s0
To | g_sound.u_perc_env_bank/gen_perc[3].level_r_7_s0
Launch Clk | clk_sys:[R]
Latch Clk | clk_sys:[R]

Data Arrival Path:

AT | DELAY | TYPE | RF | FANOUT | LOC | NODE
0.000 | 0.000 | | | | | active clock edge time
0.000 | 0.000 | | | | | clk_sys
0.000 | 0.000 | tCL | RR | 1 | IOB117[B] | clk_ibuf/I
0.952 | 0.952 | tINS | RR | 17271 | IOB117[B] | clk_ibuf/O
2.186 | 1.234 | tNET | RR | 1 | R13C94[0][A] | g_sound.u_perc_env_bank/gen_perc[3].level_r_7_s0/CLK
2.313 | 0.127 | tC2Q | RF | 6 | R13C94[0][A] | g_sound.u_perc_env_bank/gen_perc[3].level_r_7_s0/Q
2.318 | 0.005 | tNET | FF | 1 | R13C94[0][A] | g_sound.u_perc_env_bank/n1219_s4/I0
2.456 | 0.138 | tINS | FF | 1 | R13C94[0][A] | g_sound.u_perc_env_bank/n1219_s4/F
2.456 | 0.000 | tNET | FF | 1 | R13C94[0][A] | g_sound.u_perc_env_bank/gen_perc[3].level_r_7_s0/D

Data Required Path:

AT | DELAY | TYPE | RF | FANOUT | LOC | NODE
0.000 | 0.000 | | | | | active clock edge time
0.000 | 0.000 | | | | | clk_sys
0.000 | 0.000 | tCL | RR | 1 | IOB117[B] | clk_ibuf/I
0.952 | 0.952 | tINS | RR | 17271 | IOB117[B] | clk_ibuf/O
2.186 | 1.234 | tNET | RR | 1 | R13C94[0][A] | g_sound.u_perc_env_bank/gen_perc[3].level_r_7_s0/CLK
2.209 | 0.022 | tHld | | 1 | R13C94[0][A] | g_sound.u_perc_env_bank/gen_perc[3].level_r_7_s0

Path Statistics:

Clock Skew | 0.000
Hold Relationship | 0.000
Logic Level | 2
Arrival Clock Path Delay | cell: 0.952, 43.558%; route: 1.234, 56.442%
Arrival Data Path Delay | cell: 0.138, 51.000%; route: 0.005, 2.000%; tC2Q: 0.127, 47.000%
Required Clock Path Delay | cell: 0.952, 43.558%; route: 1.234, 56.442%

### Path20

Path Summary:

Slack | 0.247
Data Arrival Time | 2.460
Data Required Time | 2.212
From | g_sound.u_perc_env_bank/gen_perc[0].level_r_1_s0
To | g_sound.u_perc_env_bank/gen_perc[0].level_r_1_s0
Launch Clk | clk_sys:[R]
Latch Clk | clk_sys:[R]

Data Arrival Path:

AT | DELAY | TYPE | RF | FANOUT | LOC | NODE
0.000 | 0.000 | | | | | active clock edge time
0.000 | 0.000 | | | | | clk_sys
0.000 | 0.000 | tCL | RR | 1 | IOB117[B] | clk_ibuf/I
0.952 | 0.952 | tINS | RR | 17271 | IOB117[B] | clk_ibuf/O
2.190 | 1.237 | tNET | RR | 1 | R12C93[1][A] | g_sound.u_perc_env_bank/gen_perc[0].level_r_1_s0/CLK
2.317 | 0.127 | tC2Q | RF | 5 | R12C93[1][A] | g_sound.u_perc_env_bank/gen_perc[0].level_r_1_s0/Q
2.322 | 0.005 | tNET | FF | 1 | R12C93[1][A] | g_sound.u_perc_env_bank/n181_s2/I2
2.460 | 0.138 | tINS | FF | 1 | R12C93[1][A] | g_sound.u_perc_env_bank/n181_s2/F
2.460 | 0.000 | tNET | FF | 1 | R12C93[1][A] | g_sound.u_perc_env_bank/gen_perc[0].level_r_1_s0/D

Data Required Path:

AT | DELAY | TYPE | RF | FANOUT | LOC | NODE
0.000 | 0.000 | | | | | active clock edge time
0.000 | 0.000 | | | | | clk_sys
0.000 | 0.000 | tCL | RR | 1 | IOB117[B] | clk_ibuf/I
0.952 | 0.952 | tINS | RR | 17271 | IOB117[B] | clk_ibuf/O
2.190 | 1.237 | tNET | RR | 1 | R12C93[1][A] | g_sound.u_perc_env_bank/gen_perc[0].level_r_1_s0/CLK
2.212 | 0.022 | tHld | | 1 | R12C93[1][A] | g_sound.u_perc_env_bank/gen_perc[0].level_r_1_s0

Path Statistics:

Clock Skew | 0.000
Hold Relationship | 0.000
Logic Level | 2
Arrival Clock Path Delay | cell: 0.952, 43.487%; route: 1.237, 56.513%
Arrival Data Path Delay | cell: 0.138, 51.000%; route: 0.005, 2.000%; tC2Q: 0.127, 47.000%
Required Clock Path Delay | cell: 0.952, 43.487%; route: 1.237, 56.513%

### Path21

Path Summary:

Slack | 0.247
Data Arrival Time | 2.456
Data Required Time | 2.209
From | g_sound.u_vibrato_lfo/slew_count_q_3_s0
To | g_sound.u_vibrato_lfo/slew_count_q_3_s0
Launch Clk | clk_sys:[R]
Latch Clk | clk_sys:[R]

Data Arrival Path:

AT | DELAY | TYPE | RF | FANOUT | LOC | NODE
0.000 | 0.000 | | | | | active clock edge time
0.000 | 0.000 | | | | | clk_sys
0.000 | 0.000 | tCL | RR | 1 | IOB117[B] | clk_ibuf/I
0.952 | 0.952 | tINS | RR | 17271 | IOB117[B] | clk_ibuf/O
2.186 | 1.234 | tNET | RR | 1 | R63C138[0][A] | g_sound.u_vibrato_lfo/slew_count_q_3_s0/CLK
2.313 | 0.127 | tC2Q | RF | 3 | R63C138[0][A] | g_sound.u_vibrato_lfo/slew_count_q_3_s0/Q
2.318 | 0.005 | tNET | FF | 1 | R63C138[0][A] | g_sound.u_vibrato_lfo/n787_s2/I2
2.456 | 0.138 | tINS | FF | 1 | R63C138[0][A] | g_sound.u_vibrato_lfo/n787_s2/F
2.456 | 0.000 | tNET | FF | 1 | R63C138[0][A] | g_sound.u_vibrato_lfo/slew_count_q_3_s0/D

Data Required Path:

AT | DELAY | TYPE | RF | FANOUT | LOC | NODE
0.000 | 0.000 | | | | | active clock edge time
0.000 | 0.000 | | | | | clk_sys
0.000 | 0.000 | tCL | RR | 1 | IOB117[B] | clk_ibuf/I
0.952 | 0.952 | tINS | RR | 17271 | IOB117[B] | clk_ibuf/O
2.186 | 1.234 | tNET | RR | 1 | R63C138[0][A] | g_sound.u_vibrato_lfo/slew_count_q_3_s0/CLK
2.209 | 0.022 | tHld | | 1 | R63C138[0][A] | g_sound.u_vibrato_lfo/slew_count_q_3_s0

Path Statistics:

Clock Skew | 0.000
Hold Relationship | 0.000
Logic Level | 2
Arrival Clock Path Delay | cell: 0.952, 43.558%; route: 1.234, 56.442%
Arrival Data Path Delay | cell: 0.138, 51.000%; route: 0.005, 2.000%; tC2Q: 0.127, 47.000%
Required Clock Path Delay | cell: 0.952, 43.558%; route: 1.234, 56.442%

### Path22

Path Summary:

Slack | 0.247
Data Arrival Time | 2.456
Data Required Time | 2.209
From | g_sound.u_vibrato_lfo/slew_count_q_12_s0
To | g_sound.u_vibrato_lfo/slew_count_q_12_s0
Launch Clk | clk_sys:[R]
Latch Clk | clk_sys:[R]

Data Arrival Path:

AT | DELAY | TYPE | RF | FANOUT | LOC | NODE
0.000 | 0.000 | | | | | active clock edge time
0.000 | 0.000 | | | | | clk_sys
0.000 | 0.000 | tCL | RR | 1 | IOB117[B] | clk_ibuf/I
0.952 | 0.952 | tINS | RR | 17271 | IOB117[B] | clk_ibuf/O
2.186 | 1.234 | tNET | RR | 1 | R59C138[0][A] | g_sound.u_vibrato_lfo/slew_count_q_12_s0/CLK
2.313 | 0.127 | tC2Q | RF | 3 | R59C138[0][A] | g_sound.u_vibrato_lfo/slew_count_q_12_s0/Q
2.318 | 0.005 | tNET | FF | 1 | R59C138[0][A] | g_sound.u_vibrato_lfo/n778_s2/I2
2.456 | 0.138 | tINS | FF | 1 | R59C138[0][A] | g_sound.u_vibrato_lfo/n778_s2/F
2.456 | 0.000 | tNET | FF | 1 | R59C138[0][A] | g_sound.u_vibrato_lfo/slew_count_q_12_s0/D

Data Required Path:

AT | DELAY | TYPE | RF | FANOUT | LOC | NODE
0.000 | 0.000 | | | | | active clock edge time
0.000 | 0.000 | | | | | clk_sys
0.000 | 0.000 | tCL | RR | 1 | IOB117[B] | clk_ibuf/I
0.952 | 0.952 | tINS | RR | 17271 | IOB117[B] | clk_ibuf/O
2.186 | 1.234 | tNET | RR | 1 | R59C138[0][A] | g_sound.u_vibrato_lfo/slew_count_q_12_s0/CLK
2.209 | 0.022 | tHld | | 1 | R59C138[0][A] | g_sound.u_vibrato_lfo/slew_count_q_12_s0

Path Statistics:

Clock Skew | 0.000
Hold Relationship | 0.000
Logic Level | 2
Arrival Clock Path Delay | cell: 0.952, 43.558%; route: 1.234, 56.442%
Arrival Data Path Delay | cell: 0.138, 51.000%; route: 0.005, 2.000%; tC2Q: 0.127, 47.000%
Required Clock Path Delay | cell: 0.952, 43.558%; route: 1.234, 56.442%

### Path23

Path Summary:

Slack | 0.247
Data Arrival Time | 2.460
Data Required Time | 2.212
From | g_sound.u_vibrato_lfo/slew_count_q_16_s0
To | g_sound.u_vibrato_lfo/slew_count_q_16_s0
Launch Clk | clk_sys:[R]
Latch Clk | clk_sys:[R]

Data Arrival Path:

AT | DELAY | TYPE | RF | FANOUT | LOC | NODE
0.000 | 0.000 | | | | | active clock edge time
0.000 | 0.000 | | | | | clk_sys
0.000 | 0.000 | tCL | RR | 1 | IOB117[B] | clk_ibuf/I
0.952 | 0.952 | tINS | RR | 17271 | IOB117[B] | clk_ibuf/O
2.190 | 1.237 | tNET | RR | 1 | R64C137[0][A] | g_sound.u_vibrato_lfo/slew_count_q_16_s0/CLK
2.317 | 0.127 | tC2Q | RF | 5 | R64C137[0][A] | g_sound.u_vibrato_lfo/slew_count_q_16_s0/Q
2.322 | 0.005 | tNET | FF | 1 | R64C137[0][A] | g_sound.u_vibrato_lfo/n774_s2/I1
2.460 | 0.138 | tINS | FF | 1 | R64C137[0][A] | g_sound.u_vibrato_lfo/n774_s2/F
2.460 | 0.000 | tNET | FF | 1 | R64C137[0][A] | g_sound.u_vibrato_lfo/slew_count_q_16_s0/D

Data Required Path:

AT | DELAY | TYPE | RF | FANOUT | LOC | NODE
0.000 | 0.000 | | | | | active clock edge time
0.000 | 0.000 | | | | | clk_sys
0.000 | 0.000 | tCL | RR | 1 | IOB117[B] | clk_ibuf/I
0.952 | 0.952 | tINS | RR | 17271 | IOB117[B] | clk_ibuf/O
2.190 | 1.237 | tNET | RR | 1 | R64C137[0][A] | g_sound.u_vibrato_lfo/slew_count_q_16_s0/CLK
2.212 | 0.022 | tHld | | 1 | R64C137[0][A] | g_sound.u_vibrato_lfo/slew_count_q_16_s0

Path Statistics:

Clock Skew | 0.000
Hold Relationship | 0.000
Logic Level | 2
Arrival Clock Path Delay | cell: 0.952, 43.487%; route: 1.237, 56.513%
Arrival Data Path Delay | cell: 0.138, 51.000%; route: 0.005, 2.000%; tC2Q: 0.127, 47.000%
Required Clock Path Delay | cell: 0.952, 43.487%; route: 1.237, 56.513%

### Path24

Path Summary:

Slack | 0.247
Data Arrival Time | 2.460
Data Required Time | 2.212
From | g_sound.u_vibrato_lfo/slew_count_q_21_s0
To | g_sound.u_vibrato_lfo/slew_count_q_21_s0
Launch Clk | clk_sys:[R]
Latch Clk | clk_sys:[R]

Data Arrival Path:

AT | DELAY | TYPE | RF | FANOUT | LOC | NODE
0.000 | 0.000 | | | | | active clock edge time
0.000 | 0.000 | | | | | clk_sys
0.000 | 0.000 | tCL | RR | 1 | IOB117[B] | clk_ibuf/I
0.952 | 0.952 | tINS | RR | 17271 | IOB117[B] | clk_ibuf/O
2.190 | 1.237 | tNET | RR | 1 | R59C137[1][A] | g_sound.u_vibrato_lfo/slew_count_q_21_s0/CLK
2.317 | 0.127 | tC2Q | RF | 3 | R59C137[1][A] | g_sound.u_vibrato_lfo/slew_count_q_21_s0/Q
2.322 | 0.005 | tNET | FF | 1 | R59C137[1][A] | g_sound.u_vibrato_lfo/n769_s2/I2
2.460 | 0.138 | tINS | FF | 1 | R59C137[1][A] | g_sound.u_vibrato_lfo/n769_s2/F
2.460 | 0.000 | tNET | FF | 1 | R59C137[1][A] | g_sound.u_vibrato_lfo/slew_count_q_21_s0/D

Data Required Path:

AT | DELAY | TYPE | RF | FANOUT | LOC | NODE
0.000 | 0.000 | | | | | active clock edge time
0.000 | 0.000 | | | | | clk_sys
0.000 | 0.000 | tCL | RR | 1 | IOB117[B] | clk_ibuf/I
0.952 | 0.952 | tINS | RR | 17271 | IOB117[B] | clk_ibuf/O
2.190 | 1.237 | tNET | RR | 1 | R59C137[1][A] | g_sound.u_vibrato_lfo/slew_count_q_21_s0/CLK
2.212 | 0.022 | tHld | | 1 | R59C137[1][A] | g_sound.u_vibrato_lfo/slew_count_q_21_s0

Path Statistics:

Clock Skew | 0.000
Hold Relationship | 0.000
Logic Level | 2
Arrival Clock Path Delay | cell: 0.952, 43.487%; route: 1.237, 56.513%
Arrival Data Path Delay | cell: 0.138, 51.000%; route: 0.005, 2.000%; tC2Q: 0.127, 47.000%
Required Clock Path Delay | cell: 0.952, 43.487%; route: 1.237, 56.513%

### Path25

Path Summary:

Slack | 0.247
Data Arrival Time | 2.456
Data Required Time | 2.209
From | g_sound.u_vibrato_lfo/slew_count_q_25_s0
To | g_sound.u_vibrato_lfo/slew_count_q_25_s0
Launch Clk | clk_sys:[R]
Latch Clk | clk_sys:[R]

Data Arrival Path:

AT | DELAY | TYPE | RF | FANOUT | LOC | NODE
0.000 | 0.000 | | | | | active clock edge time
0.000 | 0.000 | | | | | clk_sys
0.000 | 0.000 | tCL | RR | 1 | IOB117[B] | clk_ibuf/I
0.952 | 0.952 | tINS | RR | 17271 | IOB117[B] | clk_ibuf/O
2.186 | 1.234 | tNET | RR | 1 | R64C138[1][A] | g_sound.u_vibrato_lfo/slew_count_q_25_s0/CLK
2.313 | 0.127 | tC2Q | RF | 4 | R64C138[1][A] | g_sound.u_vibrato_lfo/slew_count_q_25_s0/Q
2.318 | 0.005 | tNET | FF | 1 | R64C138[1][A] | g_sound.u_vibrato_lfo/n765_s2/I1
2.456 | 0.138 | tINS | FF | 1 | R64C138[1][A] | g_sound.u_vibrato_lfo/n765_s2/F
2.456 | 0.000 | tNET | FF | 1 | R64C138[1][A] | g_sound.u_vibrato_lfo/slew_count_q_25_s0/D

Data Required Path:

AT | DELAY | TYPE | RF | FANOUT | LOC | NODE
0.000 | 0.000 | | | | | active clock edge time
0.000 | 0.000 | | | | | clk_sys
0.000 | 0.000 | tCL | RR | 1 | IOB117[B] | clk_ibuf/I
0.952 | 0.952 | tINS | RR | 17271 | IOB117[B] | clk_ibuf/O
2.186 | 1.234 | tNET | RR | 1 | R64C138[1][A] | g_sound.u_vibrato_lfo/slew_count_q_25_s0/CLK
2.209 | 0.022 | tHld | | 1 | R64C138[1][A] | g_sound.u_vibrato_lfo/slew_count_q_25_s0

Path Statistics:

Clock Skew | 0.000
Hold Relationship | 0.000
Logic Level | 2
Arrival Clock Path Delay | cell: 0.952, 43.558%; route: 1.234, 56.442%
Arrival Data Path Delay | cell: 0.138, 51.000%; route: 0.005, 2.000%; tC2Q: 0.127, 47.000%
Required Clock Path Delay | cell: 0.952, 43.558%; route: 1.234, 56.442%

### Recovery Analysis Report

#### Report Command:report_timing -recovery -max_paths 25 -max_common_paths 1

### Path1

Path Summary:

Slack | 0.158
Data Arrival Time | 7.839
Data Required Time | 7.998
From | u_hdmi/rstn_ser_2_s0
To | u_hdmi/u_serializer/lanes[1].u_oser
Launch Clk | serial_clk:[R]
Latch Clk | serial_clk:[F]

Data Arrival Path:

AT | DELAY | TYPE | RF | FANOUT | LOC | NODE
0.000 | 0.000 | | | | | active clock edge time
0.000 | 0.000 | | | | | serial_clk
4.133 | 4.133 | tCL | RR | 7 | PLL_R[1] | u_hdmi/u_clk/u_pll/CLKOUT0
6.804 | 2.671 | tNET | RR | 1 | R34C146[0][A] | u_hdmi/rstn_ser_2_s0/CLK
7.135 | 0.331 | tC2Q | RF | 4 | R34C146[0][A] | u_hdmi/rstn_ser_2_s0/Q
7.839 | 0.704 | tNET | FF | 1 | IOR22[A] | u_hdmi/u_serializer/lanes[1].u_oser/RESET

Data Required Path:

AT | DELAY | TYPE | RF | FANOUT | LOC | NODE
4.000 | 4.000 | | | | | active clock edge time
4.000 | 0.000 | | | | | serial_clk
8.133 | 4.133 | tCL | FF | 7 | PLL_R[1] | u_hdmi/u_clk/u_pll/CLKOUT0
8.133 | 0.000 | tNET | FF | 1 | IOR22[A] | u_hdmi/u_serializer/lanes[1].u_oser/FCLK
7.998 | -0.136 | tSu | | 1 | IOR22[A] | u_hdmi/u_serializer/lanes[1].u_oser

Path Statistics:

Clock Skew | -2.671
Setup Relationship | 4.000
Logic Level | 1
Arrival Clock Path Delay | cell: 0.000, 0.000%; route: 2.671, 100.000%
Arrival Data Path Delay | cell: 0.000, 0.000%; route: 0.704, 68.043%; tC2Q: 0.331, 31.957%
Required Clock Path Delay | cell: 0.000, 0.000%; route: 0.000, 0.000%

### Path2

Path Summary:

Slack | 0.159
Data Arrival Time | 7.838
Data Required Time | 7.998
From | u_hdmi/rstn_ser_2_s0
To | u_hdmi/u_serializer/lanes[2].u_oser
Launch Clk | serial_clk:[R]
Latch Clk | serial_clk:[F]

Data Arrival Path:

AT | DELAY | TYPE | RF | FANOUT | LOC | NODE
0.000 | 0.000 | | | | | active clock edge time
0.000 | 0.000 | | | | | serial_clk
4.133 | 4.133 | tCL | RR | 7 | PLL_R[1] | u_hdmi/u_clk/u_pll/CLKOUT0
6.804 | 2.671 | tNET | RR | 1 | R34C146[0][A] | u_hdmi/rstn_ser_2_s0/CLK
7.135 | 0.331 | tC2Q | RF | 4 | R34C146[0][A] | u_hdmi/rstn_ser_2_s0/Q
7.838 | 0.703 | tNET | FF | 1 | IOR39[A] | u_hdmi/u_serializer/lanes[2].u_oser/RESET

Data Required Path:

AT | DELAY | TYPE | RF | FANOUT | LOC | NODE
4.000 | 4.000 | | | | | active clock edge time
4.000 | 0.000 | | | | | serial_clk
8.133 | 4.133 | tCL | FF | 7 | PLL_R[1] | u_hdmi/u_clk/u_pll/CLKOUT0
8.133 | 0.000 | tNET | FF | 1 | IOR39[A] | u_hdmi/u_serializer/lanes[2].u_oser/FCLK
7.998 | -0.136 | tSu | | 1 | IOR39[A] | u_hdmi/u_serializer/lanes[2].u_oser

Path Statistics:

Clock Skew | -2.671
Setup Relationship | 4.000
Logic Level | 1
Arrival Clock Path Delay | cell: 0.000, 0.000%; route: 2.671, 100.000%
Arrival Data Path Delay | cell: 0.000, 0.000%; route: 0.703, 68.009%; tC2Q: 0.331, 31.991%
Required Clock Path Delay | cell: 0.000, 0.000%; route: 0.000, 0.000%

### Path3

Path Summary:

Slack | 0.273
Data Arrival Time | 7.724
Data Required Time | 7.998
From | u_hdmi/rstn_ser_2_s0
To | u_hdmi/u_serializer/lanes[0].u_oser
Launch Clk | serial_clk:[R]
Latch Clk | serial_clk:[F]

Data Arrival Path:

AT | DELAY | TYPE | RF | FANOUT | LOC | NODE
0.000 | 0.000 | | | | | active clock edge time
0.000 | 0.000 | | | | | serial_clk
4.133 | 4.133 | tCL | RR | 7 | PLL_R[1] | u_hdmi/u_clk/u_pll/CLKOUT0
6.804 | 2.671 | tNET | RR | 1 | R34C146[0][A] | u_hdmi/rstn_ser_2_s0/CLK
7.135 | 0.331 | tC2Q | RF | 4 | R34C146[0][A] | u_hdmi/rstn_ser_2_s0/Q
7.724 | 0.589 | tNET | FF | 1 | IOR26[A] | u_hdmi/u_serializer/lanes[0].u_oser/RESET

Data Required Path:

AT | DELAY | TYPE | RF | FANOUT | LOC | NODE
4.000 | 4.000 | | | | | active clock edge time
4.000 | 0.000 | | | | | serial_clk
8.133 | 4.133 | tCL | FF | 7 | PLL_R[1] | u_hdmi/u_clk/u_pll/CLKOUT0
8.133 | 0.000 | tNET | FF | 1 | IOR26[A] | u_hdmi/u_serializer/lanes[0].u_oser/FCLK
7.998 | -0.136 | tSu | | 1 | IOR26[A] | u_hdmi/u_serializer/lanes[0].u_oser

Path Statistics:

Clock Skew | -2.671
Setup Relationship | 4.000
Logic Level | 1
Arrival Clock Path Delay | cell: 0.000, 0.000%; route: 2.671, 100.000%
Arrival Data Path Delay | cell: 0.000, 0.000%; route: 0.589, 64.059%; tC2Q: 0.331, 35.941%
Required Clock Path Delay | cell: 0.000, 0.000%; route: 0.000, 0.000%

### Path4

Path Summary:

Slack | 0.299
Data Arrival Time | 7.699
Data Required Time | 7.998
From | u_hdmi/rstn_ser_2_s0
To | u_hdmi/u_serializer/lanes[3].u_oser
Launch Clk | serial_clk:[R]
Latch Clk | serial_clk:[F]

Data Arrival Path:

AT | DELAY | TYPE | RF | FANOUT | LOC | NODE
0.000 | 0.000 | | | | | active clock edge time
0.000 | 0.000 | | | | | serial_clk
4.133 | 4.133 | tCL | RR | 7 | PLL_R[1] | u_hdmi/u_clk/u_pll/CLKOUT0
6.804 | 2.671 | tNET | RR | 1 | R34C146[0][A] | u_hdmi/rstn_ser_2_s0/CLK
7.135 | 0.331 | tC2Q | RF | 4 | R34C146[0][A] | u_hdmi/rstn_ser_2_s0/Q
7.699 | 0.564 | tNET | FF | 1 | IOR24[A] | u_hdmi/u_serializer/lanes[3].u_oser/RESET

Data Required Path:

AT | DELAY | TYPE | RF | FANOUT | LOC | NODE
4.000 | 4.000 | | | | | active clock edge time
4.000 | 0.000 | | | | | serial_clk
8.133 | 4.133 | tCL | FF | 7 | PLL_R[1] | u_hdmi/u_clk/u_pll/CLKOUT0
8.133 | 0.000 | tNET | FF | 1 | IOR24[A] | u_hdmi/u_serializer/lanes[3].u_oser/FCLK
7.998 | -0.136 | tSu | | 1 | IOR24[A] | u_hdmi/u_serializer/lanes[3].u_oser

Path Statistics:

Clock Skew | -2.671
Setup Relationship | 4.000
Logic Level | 1
Arrival Clock Path Delay | cell: 0.000, 0.000%; route: 2.671, 100.000%
Arrival Data Path Delay | cell: 0.000, 0.000%; route: 0.564, 63.019%; tC2Q: 0.331, 36.981%
Required Clock Path Delay | cell: 0.000, 0.000%; route: 0.000, 0.000%

### Path5

Path Summary:

Slack | 4.157
Data Arrival Time | 7.839
Data Required Time | 11.996
From | u_hdmi/rstn_ser_2_s0
To | u_hdmi/u_serializer/lanes[1].u_oser
Launch Clk | serial_clk:[R]
Latch Clk | serial_clk:[R]

Data Arrival Path:

AT | DELAY | TYPE | RF | FANOUT | LOC | NODE
0.000 | 0.000 | | | | | active clock edge time
0.000 | 0.000 | | | | | serial_clk
4.133 | 4.133 | tCL | RR | 7 | PLL_R[1] | u_hdmi/u_clk/u_pll/CLKOUT0
6.804 | 2.671 | tNET | RR | 1 | R34C146[0][A] | u_hdmi/rstn_ser_2_s0/CLK
7.135 | 0.331 | tC2Q | RF | 4 | R34C146[0][A] | u_hdmi/rstn_ser_2_s0/Q
7.839 | 0.704 | tNET | FF | 1 | IOR22[A] | u_hdmi/u_serializer/lanes[1].u_oser/RESET

Data Required Path:

AT | DELAY | TYPE | RF | FANOUT | LOC | NODE
8.000 | 8.000 | | | | | active clock edge time
8.000 | 0.000 | | | | | serial_clk
12.133 | 4.133 | tCL | RR | 7 | PLL_R[1] | u_hdmi/u_clk/u_pll/CLKOUT0
12.133 | 0.000 | tNET | RR | 1 | IOR22[A] | u_hdmi/u_serializer/lanes[1].u_oser/FCLK
11.996 | -0.138 | tSu | | 1 | IOR22[A] | u_hdmi/u_serializer/lanes[1].u_oser

Path Statistics:

Clock Skew | -2.671
Setup Relationship | 8.000
Logic Level | 1
Arrival Clock Path Delay | cell: 0.000, 0.000%; route: 2.671, 100.000%
Arrival Data Path Delay | cell: 0.000, 0.000%; route: 0.704, 68.043%; tC2Q: 0.331, 31.957%
Required Clock Path Delay | cell: 0.000, 0.000%; route: 0.000, 0.000%

### Path6

Path Summary:

Slack | 4.158
Data Arrival Time | 7.838
Data Required Time | 11.996
From | u_hdmi/rstn_ser_2_s0
To | u_hdmi/u_serializer/lanes[2].u_oser
Launch Clk | serial_clk:[R]
Latch Clk | serial_clk:[R]

Data Arrival Path:

AT | DELAY | TYPE | RF | FANOUT | LOC | NODE
0.000 | 0.000 | | | | | active clock edge time
0.000 | 0.000 | | | | | serial_clk
4.133 | 4.133 | tCL | RR | 7 | PLL_R[1] | u_hdmi/u_clk/u_pll/CLKOUT0
6.804 | 2.671 | tNET | RR | 1 | R34C146[0][A] | u_hdmi/rstn_ser_2_s0/CLK
7.135 | 0.331 | tC2Q | RF | 4 | R34C146[0][A] | u_hdmi/rstn_ser_2_s0/Q
7.838 | 0.703 | tNET | FF | 1 | IOR39[A] | u_hdmi/u_serializer/lanes[2].u_oser/RESET

Data Required Path:

AT | DELAY | TYPE | RF | FANOUT | LOC | NODE
8.000 | 8.000 | | | | | active clock edge time
8.000 | 0.000 | | | | | serial_clk
12.133 | 4.133 | tCL | RR | 7 | PLL_R[1] | u_hdmi/u_clk/u_pll/CLKOUT0
12.133 | 0.000 | tNET | RR | 1 | IOR39[A] | u_hdmi/u_serializer/lanes[2].u_oser/FCLK
11.996 | -0.138 | tSu | | 1 | IOR39[A] | u_hdmi/u_serializer/lanes[2].u_oser

Path Statistics:

Clock Skew | -2.671
Setup Relationship | 8.000
Logic Level | 1
Arrival Clock Path Delay | cell: 0.000, 0.000%; route: 2.671, 100.000%
Arrival Data Path Delay | cell: 0.000, 0.000%; route: 0.703, 68.009%; tC2Q: 0.331, 31.991%
Required Clock Path Delay | cell: 0.000, 0.000%; route: 0.000, 0.000%

### Path7

Path Summary:

Slack | 4.271
Data Arrival Time | 7.724
Data Required Time | 11.996
From | u_hdmi/rstn_ser_2_s0
To | u_hdmi/u_serializer/lanes[0].u_oser
Launch Clk | serial_clk:[R]
Latch Clk | serial_clk:[R]

Data Arrival Path:

AT | DELAY | TYPE | RF | FANOUT | LOC | NODE
0.000 | 0.000 | | | | | active clock edge time
0.000 | 0.000 | | | | | serial_clk
4.133 | 4.133 | tCL | RR | 7 | PLL_R[1] | u_hdmi/u_clk/u_pll/CLKOUT0
6.804 | 2.671 | tNET | RR | 1 | R34C146[0][A] | u_hdmi/rstn_ser_2_s0/CLK
7.135 | 0.331 | tC2Q | RF | 4 | R34C146[0][A] | u_hdmi/rstn_ser_2_s0/Q
7.724 | 0.589 | tNET | FF | 1 | IOR26[A] | u_hdmi/u_serializer/lanes[0].u_oser/RESET

Data Required Path:

AT | DELAY | TYPE | RF | FANOUT | LOC | NODE
8.000 | 8.000 | | | | | active clock edge time
8.000 | 0.000 | | | | | serial_clk
12.133 | 4.133 | tCL | RR | 7 | PLL_R[1] | u_hdmi/u_clk/u_pll/CLKOUT0
12.133 | 0.000 | tNET | RR | 1 | IOR26[A] | u_hdmi/u_serializer/lanes[0].u_oser/FCLK
11.996 | -0.138 | tSu | | 1 | IOR26[A] | u_hdmi/u_serializer/lanes[0].u_oser

Path Statistics:

Clock Skew | -2.671
Setup Relationship | 8.000
Logic Level | 1
Arrival Clock Path Delay | cell: 0.000, 0.000%; route: 2.671, 100.000%
Arrival Data Path Delay | cell: 0.000, 0.000%; route: 0.589, 64.059%; tC2Q: 0.331, 35.941%
Required Clock Path Delay | cell: 0.000, 0.000%; route: 0.000, 0.000%

### Path8

Path Summary:

Slack | 4.297
Data Arrival Time | 7.699
Data Required Time | 11.996
From | u_hdmi/rstn_ser_2_s0
To | u_hdmi/u_serializer/lanes[3].u_oser
Launch Clk | serial_clk:[R]
Latch Clk | serial_clk:[R]

Data Arrival Path:

AT | DELAY | TYPE | RF | FANOUT | LOC | NODE
0.000 | 0.000 | | | | | active clock edge time
0.000 | 0.000 | | | | | serial_clk
4.133 | 4.133 | tCL | RR | 7 | PLL_R[1] | u_hdmi/u_clk/u_pll/CLKOUT0
6.804 | 2.671 | tNET | RR | 1 | R34C146[0][A] | u_hdmi/rstn_ser_2_s0/CLK
7.135 | 0.331 | tC2Q | RF | 4 | R34C146[0][A] | u_hdmi/rstn_ser_2_s0/Q
7.699 | 0.564 | tNET | FF | 1 | IOR24[A] | u_hdmi/u_serializer/lanes[3].u_oser/RESET

Data Required Path:

AT | DELAY | TYPE | RF | FANOUT | LOC | NODE
8.000 | 8.000 | | | | | active clock edge time
8.000 | 0.000 | | | | | serial_clk
12.133 | 4.133 | tCL | RR | 7 | PLL_R[1] | u_hdmi/u_clk/u_pll/CLKOUT0
12.133 | 0.000 | tNET | RR | 1 | IOR24[A] | u_hdmi/u_serializer/lanes[3].u_oser/FCLK
11.996 | -0.138 | tSu | | 1 | IOR24[A] | u_hdmi/u_serializer/lanes[3].u_oser

Path Statistics:

Clock Skew | -2.671
Setup Relationship | 8.000
Logic Level | 1
Arrival Clock Path Delay | cell: 0.000, 0.000%; route: 2.671, 100.000%
Arrival Data Path Delay | cell: 0.000, 0.000%; route: 0.564, 63.019%; tC2Q: 0.331, 36.981%
Required Clock Path Delay | cell: 0.000, 0.000%; route: 0.000, 0.000%

### Path9

Path Summary:

Slack | 6.003
Data Arrival Time | 39.839
Data Required Time | 45.842
From | u_hdmi/rstn_ser_2_s0
To | u_hdmi/u_serializer/lanes[1].u_oser
Launch Clk | serial_clk:[R]
Latch Clk | pixel_clk:[R]

Data Arrival Path:

AT | DELAY | TYPE | RF | FANOUT | LOC | NODE
32.000 | 32.000 | | | | | active clock edge time
32.000 | 0.000 | | | | | serial_clk
36.133 | 4.133 | tCL | RR | 7 | PLL_R[1] | u_hdmi/u_clk/u_pll/CLKOUT0
38.804 | 2.671 | tNET | RR | 1 | R34C146[0][A] | u_hdmi/rstn_ser_2_s0/CLK
39.135 | 0.331 | tC2Q | RF | 4 | R34C146[0][A] | u_hdmi/rstn_ser_2_s0/Q
39.839 | 0.704 | tNET | FF | 1 | IOR22[A] | u_hdmi/u_serializer/lanes[1].u_oser/RESET

Data Required Path:

AT | DELAY | TYPE | RF | FANOUT | LOC | NODE
40.000 | 40.000 | | | | | active clock edge time
40.000 | 0.000 | | | | | pixel_clk
44.133 | 4.133 | tCL | RR | 336 | PLL_R[1] | u_hdmi/u_clk/u_pll/CLKOUT1
46.014 | 1.881 | tNET | RR | 1 | IOR22[A] | u_hdmi/u_serializer/lanes[1].u_oser/PCLK
45.979 | -0.035 | tUnc
45.842 | -0.138 | tSu | | 1 | IOR22[A] | u_hdmi/u_serializer/lanes[1].u_oser

Path Statistics:

Clock Skew | -0.790
Setup Relationship | 8.000
Logic Level | 1
Arrival Clock Path Delay | cell: 0.000, 0.000%; route: 2.671, 100.000%
Arrival Data Path Delay | cell: 0.000, 0.000%; route: 0.704, 68.043%; tC2Q: 0.331, 31.957%
Required Clock Path Delay | cell: 0.000, 0.000%; route: 1.881, 100.000%

### Path10

Path Summary:

Slack | 6.004
Data Arrival Time | 39.838
Data Required Time | 45.842
From | u_hdmi/rstn_ser_2_s0
To | u_hdmi/u_serializer/lanes[2].u_oser
Launch Clk | serial_clk:[R]
Latch Clk | pixel_clk:[R]

Data Arrival Path:

AT | DELAY | TYPE | RF | FANOUT | LOC | NODE
32.000 | 32.000 | | | | | active clock edge time
32.000 | 0.000 | | | | | serial_clk
36.133 | 4.133 | tCL | RR | 7 | PLL_R[1] | u_hdmi/u_clk/u_pll/CLKOUT0
38.804 | 2.671 | tNET | RR | 1 | R34C146[0][A] | u_hdmi/rstn_ser_2_s0/CLK
39.135 | 0.331 | tC2Q | RF | 4 | R34C146[0][A] | u_hdmi/rstn_ser_2_s0/Q
39.838 | 0.703 | tNET | FF | 1 | IOR39[A] | u_hdmi/u_serializer/lanes[2].u_oser/RESET

Data Required Path:

AT | DELAY | TYPE | RF | FANOUT | LOC | NODE
40.000 | 40.000 | | | | | active clock edge time
40.000 | 0.000 | | | | | pixel_clk
44.133 | 4.133 | tCL | RR | 336 | PLL_R[1] | u_hdmi/u_clk/u_pll/CLKOUT1
46.014 | 1.881 | tNET | RR | 1 | IOR39[A] | u_hdmi/u_serializer/lanes[2].u_oser/PCLK
45.979 | -0.035 | tUnc
45.842 | -0.138 | tSu | | 1 | IOR39[A] | u_hdmi/u_serializer/lanes[2].u_oser

Path Statistics:

Clock Skew | -0.790
Setup Relationship | 8.000
Logic Level | 1
Arrival Clock Path Delay | cell: 0.000, 0.000%; route: 2.671, 100.000%
Arrival Data Path Delay | cell: 0.000, 0.000%; route: 0.703, 68.009%; tC2Q: 0.331, 31.991%
Required Clock Path Delay | cell: 0.000, 0.000%; route: 1.881, 100.000%

### Path11

Path Summary:

Slack | 6.117
Data Arrival Time | 39.724
Data Required Time | 45.842
From | u_hdmi/rstn_ser_2_s0
To | u_hdmi/u_serializer/lanes[0].u_oser
Launch Clk | serial_clk:[R]
Latch Clk | pixel_clk:[R]

Data Arrival Path:

AT | DELAY | TYPE | RF | FANOUT | LOC | NODE
32.000 | 32.000 | | | | | active clock edge time
32.000 | 0.000 | | | | | serial_clk
36.133 | 4.133 | tCL | RR | 7 | PLL_R[1] | u_hdmi/u_clk/u_pll/CLKOUT0
38.804 | 2.671 | tNET | RR | 1 | R34C146[0][A] | u_hdmi/rstn_ser_2_s0/CLK
39.135 | 0.331 | tC2Q | RF | 4 | R34C146[0][A] | u_hdmi/rstn_ser_2_s0/Q
39.724 | 0.589 | tNET | FF | 1 | IOR26[A] | u_hdmi/u_serializer/lanes[0].u_oser/RESET

Data Required Path:

AT | DELAY | TYPE | RF | FANOUT | LOC | NODE
40.000 | 40.000 | | | | | active clock edge time
40.000 | 0.000 | | | | | pixel_clk
44.133 | 4.133 | tCL | RR | 336 | PLL_R[1] | u_hdmi/u_clk/u_pll/CLKOUT1
46.014 | 1.881 | tNET | RR | 1 | IOR26[A] | u_hdmi/u_serializer/lanes[0].u_oser/PCLK
45.979 | -0.035 | tUnc
45.842 | -0.138 | tSu | | 1 | IOR26[A] | u_hdmi/u_serializer/lanes[0].u_oser

Path Statistics:

Clock Skew | -0.790
Setup Relationship | 8.000
Logic Level | 1
Arrival Clock Path Delay | cell: 0.000, 0.000%; route: 2.671, 100.000%
Arrival Data Path Delay | cell: 0.000, 0.000%; route: 0.589, 64.059%; tC2Q: 0.331, 35.941%
Required Clock Path Delay | cell: 0.000, 0.000%; route: 1.881, 100.000%

### Path12

Path Summary:

Slack | 6.143
Data Arrival Time | 39.699
Data Required Time | 45.842
From | u_hdmi/rstn_ser_2_s0
To | u_hdmi/u_serializer/lanes[3].u_oser
Launch Clk | serial_clk:[R]
Latch Clk | pixel_clk:[R]

Data Arrival Path:

AT | DELAY | TYPE | RF | FANOUT | LOC | NODE
32.000 | 32.000 | | | | | active clock edge time
32.000 | 0.000 | | | | | serial_clk
36.133 | 4.133 | tCL | RR | 7 | PLL_R[1] | u_hdmi/u_clk/u_pll/CLKOUT0
38.804 | 2.671 | tNET | RR | 1 | R34C146[0][A] | u_hdmi/rstn_ser_2_s0/CLK
39.135 | 0.331 | tC2Q | RF | 4 | R34C146[0][A] | u_hdmi/rstn_ser_2_s0/Q
39.699 | 0.564 | tNET | FF | 1 | IOR24[A] | u_hdmi/u_serializer/lanes[3].u_oser/RESET

Data Required Path:

AT | DELAY | TYPE | RF | FANOUT | LOC | NODE
40.000 | 40.000 | | | | | active clock edge time
40.000 | 0.000 | | | | | pixel_clk
44.133 | 4.133 | tCL | RR | 336 | PLL_R[1] | u_hdmi/u_clk/u_pll/CLKOUT1
46.014 | 1.881 | tNET | RR | 1 | IOR24[A] | u_hdmi/u_serializer/lanes[3].u_oser/PCLK
45.979 | -0.035 | tUnc
45.842 | -0.138 | tSu | | 1 | IOR24[A] | u_hdmi/u_serializer/lanes[3].u_oser

Path Statistics:

Clock Skew | -0.790
Setup Relationship | 8.000
Logic Level | 1
Arrival Clock Path Delay | cell: 0.000, 0.000%; route: 2.671, 100.000%
Arrival Data Path Delay | cell: 0.000, 0.000%; route: 0.564, 63.019%; tC2Q: 0.331, 36.981%
Required Clock Path Delay | cell: 0.000, 0.000%; route: 1.881, 100.000%

### Removal Analysis Report

#### Report Command:report_timing -removal -max_paths 25 -max_common_paths 1

### Path1

Path Summary:

Slack | 0.488
Data Arrival Time | 43.449
Data Required Time | 42.961
From | u_hdmi/rstn_ser_2_s0
To | u_hdmi/u_serializer/lanes[3].u_oser
Launch Clk | serial_clk:[R]
Latch Clk | pixel_clk:[R]

Data Arrival Path:

AT | DELAY | TYPE | RF | FANOUT | LOC | NODE
40.000 | 40.000 | | | | | active clock edge time
40.000 | 0.000 | | | | | serial_clk
42.186 | 2.186 | tCL | RR | 7 | PLL_R[1] | u_hdmi/u_clk/u_pll/CLKOUT0
43.113 | 0.927 | tNET | RR | 1 | R34C146[0][A] | u_hdmi/rstn_ser_2_s0/CLK
43.243 | 0.130 | tC2Q | RR | 4 | R34C146[0][A] | u_hdmi/rstn_ser_2_s0/Q
43.449 | 0.206 | tNET | RR | 1 | IOR24[A] | u_hdmi/u_serializer/lanes[3].u_oser/RESET

Data Required Path:

AT | DELAY | TYPE | RF | FANOUT | LOC | NODE
40.000 | 40.000 | | | | | active clock edge time
40.000 | 0.000 | | | | | pixel_clk
42.186 | 2.186 | tCL | RR | 336 | PLL_R[1] | u_hdmi/u_clk/u_pll/CLKOUT1
42.788 | 0.602 | tNET | RR | 1 | IOR24[A] | u_hdmi/u_serializer/lanes[3].u_oser/PCLK
42.823 | 0.035 | tUnc
42.961 | 0.138 | tHld | | 1 | IOR24[A] | u_hdmi/u_serializer/lanes[3].u_oser

Path Statistics:

Clock Skew | -0.325
Hold Relationship | 0.000
Logic Level | 1
Arrival Clock Path Delay | cell: 0.000, 0.000%; route: 0.927, 100.000%
Arrival Data Path Delay | cell: 0.000, 0.000%; route: 0.206, 61.394%; tC2Q: 0.130, 38.606%
Required Clock Path Delay | cell: 0.000, 0.000%; route: 0.602, 100.000%

### Path2

Path Summary:

Slack | 0.501
Data Arrival Time | 43.462
Data Required Time | 42.961
From | u_hdmi/rstn_ser_2_s0
To | u_hdmi/u_serializer/lanes[2].u_oser
Launch Clk | serial_clk:[R]
Latch Clk | pixel_clk:[R]

Data Arrival Path:

AT | DELAY | TYPE | RF | FANOUT | LOC | NODE
40.000 | 40.000 | | | | | active clock edge time
40.000 | 0.000 | | | | | serial_clk
42.186 | 2.186 | tCL | RR | 7 | PLL_R[1] | u_hdmi/u_clk/u_pll/CLKOUT0
43.113 | 0.927 | tNET | RR | 1 | R34C146[0][A] | u_hdmi/rstn_ser_2_s0/CLK
43.243 | 0.130 | tC2Q | RR | 4 | R34C146[0][A] | u_hdmi/rstn_ser_2_s0/Q
43.462 | 0.220 | tNET | RR | 1 | IOR39[A] | u_hdmi/u_serializer/lanes[2].u_oser/RESET

Data Required Path:

AT | DELAY | TYPE | RF | FANOUT | LOC | NODE
40.000 | 40.000 | | | | | active clock edge time
40.000 | 0.000 | | | | | pixel_clk
42.186 | 2.186 | tCL | RR | 336 | PLL_R[1] | u_hdmi/u_clk/u_pll/CLKOUT1
42.788 | 0.602 | tNET | RR | 1 | IOR39[A] | u_hdmi/u_serializer/lanes[2].u_oser/PCLK
42.823 | 0.035 | tUnc
42.961 | 0.138 | tHld | | 1 | IOR39[A] | u_hdmi/u_serializer/lanes[2].u_oser

Path Statistics:

Clock Skew | -0.325
Hold Relationship | 0.000
Logic Level | 1
Arrival Clock Path Delay | cell: 0.000, 0.000%; route: 0.927, 100.000%
Arrival Data Path Delay | cell: 0.000, 0.000%; route: 0.220, 62.887%; tC2Q: 0.130, 37.113%
Required Clock Path Delay | cell: 0.000, 0.000%; route: 0.602, 100.000%

### Path3

Path Summary:

Slack | 0.501
Data Arrival Time | 43.462
Data Required Time | 42.961
From | u_hdmi/rstn_ser_2_s0
To | u_hdmi/u_serializer/lanes[0].u_oser
Launch Clk | serial_clk:[R]
Latch Clk | pixel_clk:[R]

Data Arrival Path:

AT | DELAY | TYPE | RF | FANOUT | LOC | NODE
40.000 | 40.000 | | | | | active clock edge time
40.000 | 0.000 | | | | | serial_clk
42.186 | 2.186 | tCL | RR | 7 | PLL_R[1] | u_hdmi/u_clk/u_pll/CLKOUT0
43.113 | 0.927 | tNET | RR | 1 | R34C146[0][A] | u_hdmi/rstn_ser_2_s0/CLK
43.243 | 0.130 | tC2Q | RR | 4 | R34C146[0][A] | u_hdmi/rstn_ser_2_s0/Q
43.462 | 0.220 | tNET | RR | 1 | IOR26[A] | u_hdmi/u_serializer/lanes[0].u_oser/RESET

Data Required Path:

AT | DELAY | TYPE | RF | FANOUT | LOC | NODE
40.000 | 40.000 | | | | | active clock edge time
40.000 | 0.000 | | | | | pixel_clk
42.186 | 2.186 | tCL | RR | 336 | PLL_R[1] | u_hdmi/u_clk/u_pll/CLKOUT1
42.788 | 0.602 | tNET | RR | 1 | IOR26[A] | u_hdmi/u_serializer/lanes[0].u_oser/PCLK
42.823 | 0.035 | tUnc
42.961 | 0.138 | tHld | | 1 | IOR26[A] | u_hdmi/u_serializer/lanes[0].u_oser

Path Statistics:

Clock Skew | -0.325
Hold Relationship | 0.000
Logic Level | 1
Arrival Clock Path Delay | cell: 0.000, 0.000%; route: 0.927, 100.000%
Arrival Data Path Delay | cell: 0.000, 0.000%; route: 0.220, 62.887%; tC2Q: 0.130, 37.113%
Required Clock Path Delay | cell: 0.000, 0.000%; route: 0.602, 100.000%

### Path4

Path Summary:

Slack | 0.569
Data Arrival Time | 43.530
Data Required Time | 42.961
From | u_hdmi/rstn_ser_2_s0
To | u_hdmi/u_serializer/lanes[1].u_oser
Launch Clk | serial_clk:[R]
Latch Clk | pixel_clk:[R]

Data Arrival Path:

AT | DELAY | TYPE | RF | FANOUT | LOC | NODE
40.000 | 40.000 | | | | | active clock edge time
40.000 | 0.000 | | | | | serial_clk
42.186 | 2.186 | tCL | RR | 7 | PLL_R[1] | u_hdmi/u_clk/u_pll/CLKOUT0
43.113 | 0.927 | tNET | RR | 1 | R34C146[0][A] | u_hdmi/rstn_ser_2_s0/CLK
43.243 | 0.130 | tC2Q | RR | 4 | R34C146[0][A] | u_hdmi/rstn_ser_2_s0/Q
43.530 | 0.287 | tNET | RR | 1 | IOR22[A] | u_hdmi/u_serializer/lanes[1].u_oser/RESET

Data Required Path:

AT | DELAY | TYPE | RF | FANOUT | LOC | NODE
40.000 | 40.000 | | | | | active clock edge time
40.000 | 0.000 | | | | | pixel_clk
42.186 | 2.186 | tCL | RR | 336 | PLL_R[1] | u_hdmi/u_clk/u_pll/CLKOUT1
42.788 | 0.602 | tNET | RR | 1 | IOR22[A] | u_hdmi/u_serializer/lanes[1].u_oser/PCLK
42.823 | 0.035 | tUnc
42.961 | 0.138 | tHld | | 1 | IOR22[A] | u_hdmi/u_serializer/lanes[1].u_oser

Path Statistics:

Clock Skew | -0.325
Hold Relationship | 0.000
Logic Level | 1
Arrival Clock Path Delay | cell: 0.000, 0.000%; route: 0.927, 100.000%
Arrival Data Path Delay | cell: 0.000, 0.000%; route: 0.287, 68.898%; tC2Q: 0.130, 31.102%
Required Clock Path Delay | cell: 0.000, 0.000%; route: 0.602, 100.000%

### Path5

Path Summary:

Slack | 1.125
Data Arrival Time | 3.449
Data Required Time | 2.324
From | u_hdmi/rstn_ser_2_s0
To | u_hdmi/u_serializer/lanes[3].u_oser
Launch Clk | serial_clk:[R]
Latch Clk | serial_clk:[R]

Data Arrival Path:

AT | DELAY | TYPE | RF | FANOUT | LOC | NODE
0.000 | 0.000 | | | | | active clock edge time
0.000 | 0.000 | | | | | serial_clk
2.186 | 2.186 | tCL | RR | 7 | PLL_R[1] | u_hdmi/u_clk/u_pll/CLKOUT0
3.113 | 0.927 | tNET | RR | 1 | R34C146[0][A] | u_hdmi/rstn_ser_2_s0/CLK
3.243 | 0.130 | tC2Q | RR | 4 | R34C146[0][A] | u_hdmi/rstn_ser_2_s0/Q
3.449 | 0.206 | tNET | RR | 1 | IOR24[A] | u_hdmi/u_serializer/lanes[3].u_oser/RESET

Data Required Path:

AT | DELAY | TYPE | RF | FANOUT | LOC | NODE
0.000 | 0.000 | | | | | active clock edge time
0.000 | 0.000 | | | | | serial_clk
2.186 | 2.186 | tCL | RR | 7 | PLL_R[1] | u_hdmi/u_clk/u_pll/CLKOUT0
2.186 | 0.000 | tNET | RR | 1 | IOR24[A] | u_hdmi/u_serializer/lanes[3].u_oser/FCLK
2.324 | 0.138 | tHld | | 1 | IOR24[A] | u_hdmi/u_serializer/lanes[3].u_oser

Path Statistics:

Clock Skew | -0.927
Hold Relationship | 0.000
Logic Level | 1
Arrival Clock Path Delay | cell: 0.000, 0.000%; route: 0.927, 100.000%
Arrival Data Path Delay | cell: 0.000, 0.000%; route: 0.206, 61.394%; tC2Q: 0.130, 38.606%
Required Clock Path Delay | cell: 0.000, 0.000%; route: 0.000, 0.000%

### Path6

Path Summary:

Slack | 1.138
Data Arrival Time | 3.462
Data Required Time | 2.324
From | u_hdmi/rstn_ser_2_s0
To | u_hdmi/u_serializer/lanes[0].u_oser
Launch Clk | serial_clk:[R]
Latch Clk | serial_clk:[R]

Data Arrival Path:

AT | DELAY | TYPE | RF | FANOUT | LOC | NODE
0.000 | 0.000 | | | | | active clock edge time
0.000 | 0.000 | | | | | serial_clk
2.186 | 2.186 | tCL | RR | 7 | PLL_R[1] | u_hdmi/u_clk/u_pll/CLKOUT0
3.113 | 0.927 | tNET | RR | 1 | R34C146[0][A] | u_hdmi/rstn_ser_2_s0/CLK
3.243 | 0.130 | tC2Q | RR | 4 | R34C146[0][A] | u_hdmi/rstn_ser_2_s0/Q
3.462 | 0.220 | tNET | RR | 1 | IOR26[A] | u_hdmi/u_serializer/lanes[0].u_oser/RESET

Data Required Path:

AT | DELAY | TYPE | RF | FANOUT | LOC | NODE
0.000 | 0.000 | | | | | active clock edge time
0.000 | 0.000 | | | | | serial_clk
2.186 | 2.186 | tCL | RR | 7 | PLL_R[1] | u_hdmi/u_clk/u_pll/CLKOUT0
2.186 | 0.000 | tNET | RR | 1 | IOR26[A] | u_hdmi/u_serializer/lanes[0].u_oser/FCLK
2.324 | 0.138 | tHld | | 1 | IOR26[A] | u_hdmi/u_serializer/lanes[0].u_oser

Path Statistics:

Clock Skew | -0.927
Hold Relationship | 0.000
Logic Level | 1
Arrival Clock Path Delay | cell: 0.000, 0.000%; route: 0.927, 100.000%
Arrival Data Path Delay | cell: 0.000, 0.000%; route: 0.220, 62.887%; tC2Q: 0.130, 37.113%
Required Clock Path Delay | cell: 0.000, 0.000%; route: 0.000, 0.000%

### Path7

Path Summary:

Slack | 1.138
Data Arrival Time | 3.462
Data Required Time | 2.324
From | u_hdmi/rstn_ser_2_s0
To | u_hdmi/u_serializer/lanes[2].u_oser
Launch Clk | serial_clk:[R]
Latch Clk | serial_clk:[R]

Data Arrival Path:

AT | DELAY | TYPE | RF | FANOUT | LOC | NODE
0.000 | 0.000 | | | | | active clock edge time
0.000 | 0.000 | | | | | serial_clk
2.186 | 2.186 | tCL | RR | 7 | PLL_R[1] | u_hdmi/u_clk/u_pll/CLKOUT0
3.113 | 0.927 | tNET | RR | 1 | R34C146[0][A] | u_hdmi/rstn_ser_2_s0/CLK
3.243 | 0.130 | tC2Q | RR | 4 | R34C146[0][A] | u_hdmi/rstn_ser_2_s0/Q
3.462 | 0.220 | tNET | RR | 1 | IOR39[A] | u_hdmi/u_serializer/lanes[2].u_oser/RESET

Data Required Path:

AT | DELAY | TYPE | RF | FANOUT | LOC | NODE
0.000 | 0.000 | | | | | active clock edge time
0.000 | 0.000 | | | | | serial_clk
2.186 | 2.186 | tCL | RR | 7 | PLL_R[1] | u_hdmi/u_clk/u_pll/CLKOUT0
2.186 | 0.000 | tNET | RR | 1 | IOR39[A] | u_hdmi/u_serializer/lanes[2].u_oser/FCLK
2.324 | 0.138 | tHld | | 1 | IOR39[A] | u_hdmi/u_serializer/lanes[2].u_oser

Path Statistics:

Clock Skew | -0.927
Hold Relationship | 0.000
Logic Level | 1
Arrival Clock Path Delay | cell: 0.000, 0.000%; route: 0.927, 100.000%
Arrival Data Path Delay | cell: 0.000, 0.000%; route: 0.220, 62.887%; tC2Q: 0.130, 37.113%
Required Clock Path Delay | cell: 0.000, 0.000%; route: 0.000, 0.000%

### Path8

Path Summary:

Slack | 1.206
Data Arrival Time | 3.530
Data Required Time | 2.324
From | u_hdmi/rstn_ser_2_s0
To | u_hdmi/u_serializer/lanes[1].u_oser
Launch Clk | serial_clk:[R]
Latch Clk | serial_clk:[R]

Data Arrival Path:

AT | DELAY | TYPE | RF | FANOUT | LOC | NODE
0.000 | 0.000 | | | | | active clock edge time
0.000 | 0.000 | | | | | serial_clk
2.186 | 2.186 | tCL | RR | 7 | PLL_R[1] | u_hdmi/u_clk/u_pll/CLKOUT0
3.113 | 0.927 | tNET | RR | 1 | R34C146[0][A] | u_hdmi/rstn_ser_2_s0/CLK
3.243 | 0.130 | tC2Q | RR | 4 | R34C146[0][A] | u_hdmi/rstn_ser_2_s0/Q
3.530 | 0.287 | tNET | RR | 1 | IOR22[A] | u_hdmi/u_serializer/lanes[1].u_oser/RESET

Data Required Path:

AT | DELAY | TYPE | RF | FANOUT | LOC | NODE
0.000 | 0.000 | | | | | active clock edge time
0.000 | 0.000 | | | | | serial_clk
2.186 | 2.186 | tCL | RR | 7 | PLL_R[1] | u_hdmi/u_clk/u_pll/CLKOUT0
2.186 | 0.000 | tNET | RR | 1 | IOR22[A] | u_hdmi/u_serializer/lanes[1].u_oser/FCLK
2.324 | 0.138 | tHld | | 1 | IOR22[A] | u_hdmi/u_serializer/lanes[1].u_oser

Path Statistics:

Clock Skew | -0.927
Hold Relationship | 0.000
Logic Level | 1
Arrival Clock Path Delay | cell: 0.000, 0.000%; route: 0.927, 100.000%
Arrival Data Path Delay | cell: 0.000, 0.000%; route: 0.287, 68.898%; tC2Q: 0.130, 31.102%
Required Clock Path Delay | cell: 0.000, 0.000%; route: 0.000, 0.000%

### Path9

Path Summary:

Slack | 5.127
Data Arrival Time | 3.449
Data Required Time | -1.678
From | u_hdmi/rstn_ser_2_s0
To | u_hdmi/u_serializer/lanes[3].u_oser
Launch Clk | serial_clk:[R]
Latch Clk | serial_clk:[F]

Data Arrival Path:

AT | DELAY | TYPE | RF | FANOUT | LOC | NODE
0.000 | 0.000 | | | | | active clock edge time
0.000 | 0.000 | | | | | serial_clk
2.186 | 2.186 | tCL | RR | 7 | PLL_R[1] | u_hdmi/u_clk/u_pll/CLKOUT0
3.113 | 0.927 | tNET | RR | 1 | R34C146[0][A] | u_hdmi/rstn_ser_2_s0/CLK
3.243 | 0.130 | tC2Q | RR | 4 | R34C146[0][A] | u_hdmi/rstn_ser_2_s0/Q
3.449 | 0.206 | tNET | RR | 1 | IOR24[A] | u_hdmi/u_serializer/lanes[3].u_oser/RESET

Data Required Path:

AT | DELAY | TYPE | RF | FANOUT | LOC | NODE
-4.000 | -4.000 | | | | | active clock edge time
-4.000 | 0.000 | | | | | serial_clk
-1.814 | 2.186 | tCL | FF | 7 | PLL_R[1] | u_hdmi/u_clk/u_pll/CLKOUT0
-1.814 | 0.000 | tNET | FF | 1 | IOR24[A] | u_hdmi/u_serializer/lanes[3].u_oser/FCLK
-1.678 | 0.136 | tHld | | 1 | IOR24[A] | u_hdmi/u_serializer/lanes[3].u_oser

Path Statistics:

Clock Skew | -0.927
Hold Relationship | -4.000
Logic Level | 1
Arrival Clock Path Delay | cell: 0.000, 0.000%; route: 0.927, 100.000%
Arrival Data Path Delay | cell: 0.000, 0.000%; route: 0.206, 61.394%; tC2Q: 0.130, 38.606%
Required Clock Path Delay | cell: 0.000, 0.000%; route: 0.000, 0.000%

### Path10

Path Summary:

Slack | 5.140
Data Arrival Time | 3.462
Data Required Time | -1.678
From | u_hdmi/rstn_ser_2_s0
To | u_hdmi/u_serializer/lanes[0].u_oser
Launch Clk | serial_clk:[R]
Latch Clk | serial_clk:[F]

Data Arrival Path:

AT | DELAY | TYPE | RF | FANOUT | LOC | NODE
0.000 | 0.000 | | | | | active clock edge time
0.000 | 0.000 | | | | | serial_clk
2.186 | 2.186 | tCL | RR | 7 | PLL_R[1] | u_hdmi/u_clk/u_pll/CLKOUT0
3.113 | 0.927 | tNET | RR | 1 | R34C146[0][A] | u_hdmi/rstn_ser_2_s0/CLK
3.243 | 0.130 | tC2Q | RR | 4 | R34C146[0][A] | u_hdmi/rstn_ser_2_s0/Q
3.462 | 0.220 | tNET | RR | 1 | IOR26[A] | u_hdmi/u_serializer/lanes[0].u_oser/RESET

Data Required Path:

AT | DELAY | TYPE | RF | FANOUT | LOC | NODE
-4.000 | -4.000 | | | | | active clock edge time
-4.000 | 0.000 | | | | | serial_clk
-1.814 | 2.186 | tCL | FF | 7 | PLL_R[1] | u_hdmi/u_clk/u_pll/CLKOUT0
-1.814 | 0.000 | tNET | FF | 1 | IOR26[A] | u_hdmi/u_serializer/lanes[0].u_oser/FCLK
-1.678 | 0.136 | tHld | | 1 | IOR26[A] | u_hdmi/u_serializer/lanes[0].u_oser

Path Statistics:

Clock Skew | -0.927
Hold Relationship | -4.000
Logic Level | 1
Arrival Clock Path Delay | cell: 0.000, 0.000%; route: 0.927, 100.000%
Arrival Data Path Delay | cell: 0.000, 0.000%; route: 0.220, 62.887%; tC2Q: 0.130, 37.113%
Required Clock Path Delay | cell: 0.000, 0.000%; route: 0.000, 0.000%

### Path11

Path Summary:

Slack | 5.140
Data Arrival Time | 3.462
Data Required Time | -1.678
From | u_hdmi/rstn_ser_2_s0
To | u_hdmi/u_serializer/lanes[2].u_oser
Launch Clk | serial_clk:[R]
Latch Clk | serial_clk:[F]

Data Arrival Path:

AT | DELAY | TYPE | RF | FANOUT | LOC | NODE
0.000 | 0.000 | | | | | active clock edge time
0.000 | 0.000 | | | | | serial_clk
2.186 | 2.186 | tCL | RR | 7 | PLL_R[1] | u_hdmi/u_clk/u_pll/CLKOUT0
3.113 | 0.927 | tNET | RR | 1 | R34C146[0][A] | u_hdmi/rstn_ser_2_s0/CLK
3.243 | 0.130 | tC2Q | RR | 4 | R34C146[0][A] | u_hdmi/rstn_ser_2_s0/Q
3.462 | 0.220 | tNET | RR | 1 | IOR39[A] | u_hdmi/u_serializer/lanes[2].u_oser/RESET

Data Required Path:

AT | DELAY | TYPE | RF | FANOUT | LOC | NODE
-4.000 | -4.000 | | | | | active clock edge time
-4.000 | 0.000 | | | | | serial_clk
-1.814 | 2.186 | tCL | FF | 7 | PLL_R[1] | u_hdmi/u_clk/u_pll/CLKOUT0
-1.814 | 0.000 | tNET | FF | 1 | IOR39[A] | u_hdmi/u_serializer/lanes[2].u_oser/FCLK
-1.678 | 0.136 | tHld | | 1 | IOR39[A] | u_hdmi/u_serializer/lanes[2].u_oser

Path Statistics:

Clock Skew | -0.927
Hold Relationship | -4.000
Logic Level | 1
Arrival Clock Path Delay | cell: 0.000, 0.000%; route: 0.927, 100.000%
Arrival Data Path Delay | cell: 0.000, 0.000%; route: 0.220, 62.887%; tC2Q: 0.130, 37.113%
Required Clock Path Delay | cell: 0.000, 0.000%; route: 0.000, 0.000%

### Path12

Path Summary:

Slack | 5.208
Data Arrival Time | 3.530
Data Required Time | -1.678
From | u_hdmi/rstn_ser_2_s0
To | u_hdmi/u_serializer/lanes[1].u_oser
Launch Clk | serial_clk:[R]
Latch Clk | serial_clk:[F]

Data Arrival Path:

AT | DELAY | TYPE | RF | FANOUT | LOC | NODE
0.000 | 0.000 | | | | | active clock edge time
0.000 | 0.000 | | | | | serial_clk
2.186 | 2.186 | tCL | RR | 7 | PLL_R[1] | u_hdmi/u_clk/u_pll/CLKOUT0
3.113 | 0.927 | tNET | RR | 1 | R34C146[0][A] | u_hdmi/rstn_ser_2_s0/CLK
3.243 | 0.130 | tC2Q | RR | 4 | R34C146[0][A] | u_hdmi/rstn_ser_2_s0/Q
3.530 | 0.287 | tNET | RR | 1 | IOR22[A] | u_hdmi/u_serializer/lanes[1].u_oser/RESET

Data Required Path:

AT | DELAY | TYPE | RF | FANOUT | LOC | NODE
-4.000 | -4.000 | | | | | active clock edge time
-4.000 | 0.000 | | | | | serial_clk
-1.814 | 2.186 | tCL | FF | 7 | PLL_R[1] | u_hdmi/u_clk/u_pll/CLKOUT0
-1.814 | 0.000 | tNET | FF | 1 | IOR22[A] | u_hdmi/u_serializer/lanes[1].u_oser/FCLK
-1.678 | 0.136 | tHld | | 1 | IOR22[A] | u_hdmi/u_serializer/lanes[1].u_oser

Path Statistics:

Clock Skew | -0.927
Hold Relationship | -4.000
Logic Level | 1
Arrival Clock Path Delay | cell: 0.000, 0.000%; route: 0.927, 100.000%
Arrival Data Path Delay | cell: 0.000, 0.000%; route: 0.287, 68.898%; tC2Q: 0.130, 31.102%
Required Clock Path Delay | cell: 0.000, 0.000%; route: 0.000, 0.000%

## Minimum Pulse Width Report:

#### Report Command:report_min_pulse_width -nworst 10 -detail

### MPW1

MPW Summary:

Slack: | 0.087
Actual Width: | 0.312
Required Width: | 0.225
Type: | Low Pulse Width
Clock: | serial_clk
Objects: | u_hdmi/rstn_ser_2_s0

Late clock Path:

AT | DELAY | TYPE | RF | NODE
4.000 | 0.000 | | | active clock edge time
4.000 | 0.000 | | | serial_clk
8.133 | 4.133 | tCL | FF | u_hdmi/u_clk/u_pll/CLKOUT0
10.801 | 2.667 | tNET | FF | u_hdmi/rstn_ser_2_s0/CLK

Early clock Path:

AT | DELAY | TYPE | RF | NODE
8.000 | 0.000 | | | active clock edge time
8.000 | 0.000 | | | serial_clk
10.186 | 2.186 | tCL | RR | u_hdmi/u_clk/u_pll/CLKOUT0
11.113 | 0.927 | tNET | RR | u_hdmi/rstn_ser_2_s0/CLK

### MPW2

MPW Summary:

Slack: | 0.087
Actual Width: | 0.312
Required Width: | 0.225
Type: | Low Pulse Width
Clock: | serial_clk
Objects: | u_hdmi/rstn_ser_1_s0

Late clock Path:

AT | DELAY | TYPE | RF | NODE
4.000 | 0.000 | | | active clock edge time
4.000 | 0.000 | | | serial_clk
8.133 | 4.133 | tCL | FF | u_hdmi/u_clk/u_pll/CLKOUT0
10.801 | 2.667 | tNET | FF | u_hdmi/rstn_ser_1_s0/CLK

Early clock Path:

AT | DELAY | TYPE | RF | NODE
8.000 | 0.000 | | | active clock edge time
8.000 | 0.000 | | | serial_clk
10.186 | 2.186 | tCL | RR | u_hdmi/u_clk/u_pll/CLKOUT0
11.113 | 0.927 | tNET | RR | u_hdmi/rstn_ser_1_s0/CLK

### MPW3

MPW Summary:

Slack: | 0.087
Actual Width: | 0.312
Required Width: | 0.225
Type: | Low Pulse Width
Clock: | serial_clk
Objects: | u_hdmi/rstn_ser_0_s0

Late clock Path:

AT | DELAY | TYPE | RF | NODE
4.000 | 0.000 | | | active clock edge time
4.000 | 0.000 | | | serial_clk
8.133 | 4.133 | tCL | FF | u_hdmi/u_clk/u_pll/CLKOUT0
10.801 | 2.667 | tNET | FF | u_hdmi/rstn_ser_0_s0/CLK

Early clock Path:

AT | DELAY | TYPE | RF | NODE
8.000 | 0.000 | | | active clock edge time
8.000 | 0.000 | | | serial_clk
10.186 | 2.186 | tCL | RR | u_hdmi/u_clk/u_pll/CLKOUT0
11.113 | 0.927 | tNET | RR | u_hdmi/rstn_ser_0_s0/CLK

### MPW4

MPW Summary:

Slack: | 0.088
Actual Width: | 0.313
Required Width: | 0.225
Type: | High Pulse Width
Clock: | serial_clk
Objects: | u_hdmi/rstn_ser_2_s0

Late clock Path:

AT | DELAY | TYPE | RF | NODE
0.000 | 0.000 | | | active clock edge time
0.000 | 0.000 | | | serial_clk
4.133 | 4.133 | tCL | RR | u_hdmi/u_clk/u_pll/CLKOUT0
6.804 | 2.671 | tNET | RR | u_hdmi/rstn_ser_2_s0/CLK

Early clock Path:

AT | DELAY | TYPE | RF | NODE
4.000 | 0.000 | | | active clock edge time
4.000 | 0.000 | | | serial_clk
6.186 | 2.186 | tCL | FF | u_hdmi/u_clk/u_pll/CLKOUT0
7.118 | 0.931 | tNET | FF | u_hdmi/rstn_ser_2_s0/CLK

### MPW5

MPW Summary:

Slack: | 0.088
Actual Width: | 0.313
Required Width: | 0.225
Type: | High Pulse Width
Clock: | serial_clk
Objects: | u_hdmi/rstn_ser_1_s0

Late clock Path:

AT | DELAY | TYPE | RF | NODE
0.000 | 0.000 | | | active clock edge time
0.000 | 0.000 | | | serial_clk
4.133 | 4.133 | tCL | RR | u_hdmi/u_clk/u_pll/CLKOUT0
6.804 | 2.671 | tNET | RR | u_hdmi/rstn_ser_1_s0/CLK

Early clock Path:

AT | DELAY | TYPE | RF | NODE
4.000 | 0.000 | | | active clock edge time
4.000 | 0.000 | | | serial_clk
6.186 | 2.186 | tCL | FF | u_hdmi/u_clk/u_pll/CLKOUT0
7.118 | 0.931 | tNET | FF | u_hdmi/rstn_ser_1_s0/CLK

### MPW6

MPW Summary:

Slack: | 0.088
Actual Width: | 0.313
Required Width: | 0.225
Type: | High Pulse Width
Clock: | serial_clk
Objects: | u_hdmi/rstn_ser_0_s0

Late clock Path:

AT | DELAY | TYPE | RF | NODE
0.000 | 0.000 | | | active clock edge time
0.000 | 0.000 | | | serial_clk
4.133 | 4.133 | tCL | RR | u_hdmi/u_clk/u_pll/CLKOUT0
6.804 | 2.671 | tNET | RR | u_hdmi/rstn_ser_0_s0/CLK

Early clock Path:

AT | DELAY | TYPE | RF | NODE
4.000 | 0.000 | | | active clock edge time
4.000 | 0.000 | | | serial_clk
6.186 | 2.186 | tCL | FF | u_hdmi/u_clk/u_pll/CLKOUT0
7.118 | 0.931 | tNET | FF | u_hdmi/rstn_ser_0_s0/CLK

### MPW7

MPW Summary:

Slack: | 6.809
Actual Width: | 7.709
Required Width: | 0.900
Type: | Low Pulse Width
Clock: | clk_sys
Objects: | g_sound.u_looper/ep_mem_ep_mem_0_1_s

Late clock Path:

AT | DELAY | TYPE | RF | NODE
10.000 | 0.000 | | | active clock edge time
10.000 | 0.000 | | | clk_sys
10.000 | 0.000 | tCL | FF | clk_ibuf/I
11.376 | 1.376 | tINS | FF | clk_ibuf/O
14.661 | 3.285 | tNET | FF | g_sound.u_looper/ep_mem_ep_mem_0_1_s/CLKB

Early clock Path:

AT | DELAY | TYPE | RF | NODE
20.000 | 0.000 | | | active clock edge time
20.000 | 0.000 | | | clk_sys
20.000 | 0.000 | tCL | RR | clk_ibuf/I
20.952 | 0.952 | tINS | RR | clk_ibuf/O
22.371 | 1.418 | tNET | RR | g_sound.u_looper/ep_mem_ep_mem_0_1_s/CLKB

### MPW8

MPW Summary:

Slack: | 6.814
Actual Width: | 7.714
Required Width: | 0.900
Type: | Low Pulse Width
Clock: | clk_sys
Objects: | g_sound.u_looper/ep_mem_ep_mem_0_1_s

Late clock Path:

AT | DELAY | TYPE | RF | NODE
10.000 | 0.000 | | | active clock edge time
10.000 | 0.000 | | | clk_sys
10.000 | 0.000 | tCL | FF | clk_ibuf/I
11.376 | 1.376 | tINS | FF | clk_ibuf/O
14.653 | 3.277 | tNET | FF | g_sound.u_looper/ep_mem_ep_mem_0_1_s/CLKA

Early clock Path:

AT | DELAY | TYPE | RF | NODE
20.000 | 0.000 | | | active clock edge time
20.000 | 0.000 | | | clk_sys
20.000 | 0.000 | tCL | RR | clk_ibuf/I
20.952 | 0.952 | tINS | RR | clk_ibuf/O
22.367 | 1.415 | tNET | RR | g_sound.u_looper/ep_mem_ep_mem_0_1_s/CLKA

### MPW9

MPW Summary:

Slack: | 6.814
Actual Width: | 7.714
Required Width: | 0.900
Type: | Low Pulse Width
Clock: | clk_sys
Objects: | g_sound.u_looper/ep_mem_ep_mem_0_2_s

Late clock Path:

AT | DELAY | TYPE | RF | NODE
10.000 | 0.000 | | | active clock edge time
10.000 | 0.000 | | | clk_sys
10.000 | 0.000 | tCL | FF | clk_ibuf/I
11.376 | 1.376 | tINS | FF | clk_ibuf/O
14.653 | 3.277 | tNET | FF | g_sound.u_looper/ep_mem_ep_mem_0_2_s/CLKB

Early clock Path:

AT | DELAY | TYPE | RF | NODE
20.000 | 0.000 | | | active clock edge time
20.000 | 0.000 | | | clk_sys
20.000 | 0.000 | tCL | RR | clk_ibuf/I
20.952 | 0.952 | tINS | RR | clk_ibuf/O
22.367 | 1.415 | tNET | RR | g_sound.u_looper/ep_mem_ep_mem_0_2_s/CLKB

### MPW10

MPW Summary:

Slack: | 6.814
Actual Width: | 7.714
Required Width: | 0.900
Type: | Low Pulse Width
Clock: | clk_sys
Objects: | g_sound.u_looper/ep_mem_ep_mem_0_3_s

Late clock Path:

AT | DELAY | TYPE | RF | NODE
10.000 | 0.000 | | | active clock edge time
10.000 | 0.000 | | | clk_sys
10.000 | 0.000 | tCL | FF | clk_ibuf/I
11.376 | 1.376 | tINS | FF | clk_ibuf/O
14.653 | 3.277 | tNET | FF | g_sound.u_looper/ep_mem_ep_mem_0_3_s/CLKA

Early clock Path:

AT | DELAY | TYPE | RF | NODE
20.000 | 0.000 | | | active clock edge time
20.000 | 0.000 | | | clk_sys
20.000 | 0.000 | tCL | RR | clk_ibuf/I
20.952 | 0.952 | tINS | RR | clk_ibuf/O
22.367 | 1.415 | tNET | RR | g_sound.u_looper/ep_mem_ep_mem_0_3_s/CLKA

## High Fanout Nets Report:

#### Report Command:report_high_fanout_nets -max_nets 10

FANOUT | NET NAME | WORST SLACK | MAX DELAY
17271 | clk_d | 0.001 | 3.307
11902 | rst_n_sync | 5.588 | 2.580
1414 | tick_audio_Z | 9.006 | 2.617
805 | g_sound.u_looper/ramp_sc[3] | 4.378 | 5.882
564 | g_t3.rot_cnt[0] | 6.317 | 3.163
491 | g_sound.af_sample_ch[2] | 2.411 | 5.212
407 | g_sound.u_looper/ramp_sc[2] | 6.057 | 4.241
391 | g_sound.am_axis_out[3] | 8.432 | 3.980
376 | g_sound.u_looper/ramp_inc_3525 | 6.953 | 3.360
368 | g_sound.u_looper/close_scan_r[3] | 8.812 | 2.050

## Route Congestions Report:

#### Report Command:report_route_congestion -max_grids 10

GRID LOC | ROUTE CONGESTIONS
R30C76 | 93.06%
R30C77 | 90.28%
R30C78 | 88.89%
R33C119 | 87.50%
R30C79 | 86.11%
R30C82 | 86.11%
R52C72 | 84.72%
R49C87 | 84.72%
R30C80 | 84.72%
R50C66 | 83.33%

## Timing Exceptions Report:

### Setup Analysis Report

#### Report Command:report_exceptions -setup -max_paths 5 -max_common_paths 1

#### Timing Path Constraint[1]: set_max_delay -from [get_clocks {clk_sys}] -to [get_clocks {clk_sys}] 17.8

### Path1

Path Summary:

Slack | 0.001
Data Arrival Time | 21.660
Data Required Time | 21.662
From | g_sound.u_note_manager/fifo_ax_fifo_ax_0_0_s
To | g_sound.u_note_manager/same_idx_r_0_s0
Launch Clk | clk_sys:[R]
Latch Clk | clk_sys:[R]

Data Arrival Path:

AT | DELAY | TYPE | RF | FANOUT | LOC | NODE
0.000 | 0.000 | | | | | active clock edge time
0.000 | 0.000 | | | | | clk_sys
0.000 | 0.000 | tCL | RR | 1 | IOB117[B] | clk_ibuf/I
1.288 | 1.288 | tINS | RR | 17271 | IOB117[B] | clk_ibuf/O
4.150 | 2.862 | tNET | RR | 16 | BSRAM_R56[11][A] | g_sound.u_note_manager/fifo_ax_fifo_ax_0_0_s/CLKB
5.959 | 1.809 | tC2Q | RR | 35 | BSRAM_R56[11][A] | g_sound.u_note_manager/fifo_ax_fifo_ax_0_0_s/DO[2]
8.563 | 2.604 | tNET | RR | 2 | R71C55[1][A] | g_sound.u_note_manager/n1777_s0/I1
9.069 | 0.506 | tINS | RF | 1 | R71C55[1][A] | g_sound.u_note_manager/n1777_s0/COUT
9.069 | 0.000 | tNET | FF | 2 | R71C55[1][B] | g_sound.u_note_manager/n1778_s0/CIN
9.114 | 0.045 | tINS | FR | 2 | R71C55[1][B] | g_sound.u_note_manager/n1778_s0/COUT
11.406 | 2.292 | tNET | RR | 1 | R37C70[3][B] | g_sound.u_note_manager/same_valid_s24/I3
11.875 | 0.469 | tINS | RR | 3 | R37C70[3][B] | g_sound.u_note_manager/same_valid_s24/F
13.024 | 1.149 | tNET | RR | 1 | R25C89[2][B] | g_sound.u_note_manager/same_valid_s11/I1
13.439 | 0.415 | tINS | RR | 3 | R25C89[2][B] | g_sound.u_note_manager/same_valid_s11/F
13.756 | 0.317 | tNET | RR | 1 | R24C90[2][A] | g_sound.u_note_manager/same_valid_s4/I0
14.221 | 0.465 | tINS | RR | 2 | R24C90[2][A] | g_sound.u_note_manager/same_valid_s4/F
14.365 | 0.144 | tNET | RR | 1 | R25C90[3][B] | g_sound.u_note_manager/same_valid_s0/I3
14.738 | 0.373 | tINS | RR | 4 | R25C90[3][B] | g_sound.u_note_manager/same_valid_s0/F
17.236 | 2.497 | tNET | RR | 1 | R61C58[3][A] | g_sound.u_note_manager/n26787_s5/I2
17.497 | 0.261 | tINS | RF | 3 | R61C58[3][A] | g_sound.u_note_manager/n26787_s5/F
17.510 | 0.014 | tNET | FF | 1 | R61C58[3][B] | g_sound.u_note_manager/n26787_s6/I3
17.884 | 0.373 | tINS | FR | 5 | R61C58[3][B] | g_sound.u_note_manager/n26787_s6/F
21.660 | 3.777 | tNET | RR | 1 | R25C91[2][B] | g_sound.u_note_manager/same_idx_r_0_s0/CE

Data Required Path:

AT | DELAY | TYPE | RF | FANOUT | LOC | NODE
17.800 | 17.800 | | | | | active clock edge time
17.800 | 0.000 | | | | | clk_sys
17.800 | 0.000 | tCL | RR | 1 | IOB117[B] | clk_ibuf/I
19.088 | 1.288 | tINS | RR | 17271 | IOB117[B] | clk_ibuf/O
21.942 | 2.854 | tNET | RR | 1 | R25C91[2][B] | g_sound.u_note_manager/same_idx_r_0_s0/CLK
21.662 | -0.280 | tSu | | 1 | R25C91[2][B] | g_sound.u_note_manager/same_idx_r_0_s0

Path Statistics:

Clock Skew | -0.008
Setup Relationship | 17.800
Logic Level | 9
Arrival Clock Path Delay | cell: 1.288, 31.042%; route: 2.862, 68.958%
Arrival Data Path Delay | cell: 2.908, 16.608%; route: 12.793, 73.060%; tC2Q: 1.809, 10.331%
Required Clock Path Delay | cell: 1.288, 31.105%; route: 2.854, 68.895%

### Path2

Path Summary:

Slack | 0.059
Data Arrival Time | 21.611
Data Required Time | 21.670
From | g_sound.u_note_manager/fifo_ax_fifo_ax_0_0_s
To | g_sound.u_note_manager/same_idx_r_1_s0
Launch Clk | clk_sys:[R]
Latch Clk | clk_sys:[R]

Data Arrival Path:

AT | DELAY | TYPE | RF | FANOUT | LOC | NODE
0.000 | 0.000 | | | | | active clock edge time
0.000 | 0.000 | | | | | clk_sys
0.000 | 0.000 | tCL | RR | 1 | IOB117[B] | clk_ibuf/I
1.288 | 1.288 | tINS | RR | 17271 | IOB117[B] | clk_ibuf/O
4.150 | 2.862 | tNET | RR | 16 | BSRAM_R56[11][A] | g_sound.u_note_manager/fifo_ax_fifo_ax_0_0_s/CLKB
5.959 | 1.809 | tC2Q | RR | 35 | BSRAM_R56[11][A] | g_sound.u_note_manager/fifo_ax_fifo_ax_0_0_s/DO[2]
8.563 | 2.604 | tNET | RR | 2 | R71C55[1][A] | g_sound.u_note_manager/n1777_s0/I1
9.069 | 0.506 | tINS | RF | 1 | R71C55[1][A] | g_sound.u_note_manager/n1777_s0/COUT
9.069 | 0.000 | tNET | FF | 2 | R71C55[1][B] | g_sound.u_note_manager/n1778_s0/CIN
9.114 | 0.045 | tINS | FR | 2 | R71C55[1][B] | g_sound.u_note_manager/n1778_s0/COUT
11.406 | 2.292 | tNET | RR | 1 | R37C70[3][B] | g_sound.u_note_manager/same_valid_s24/I3
11.875 | 0.469 | tINS | RR | 3 | R37C70[3][B] | g_sound.u_note_manager/same_valid_s24/F
13.024 | 1.149 | tNET | RR | 1 | R25C89[2][B] | g_sound.u_note_manager/same_valid_s11/I1
13.439 | 0.415 | tINS | RR | 3 | R25C89[2][B] | g_sound.u_note_manager/same_valid_s11/F
13.756 | 0.317 | tNET | RR | 1 | R24C90[2][A] | g_sound.u_note_manager/same_valid_s4/I0
14.221 | 0.465 | tINS | RR | 2 | R24C90[2][A] | g_sound.u_note_manager/same_valid_s4/F
14.365 | 0.144 | tNET | RR | 1 | R25C90[3][B] | g_sound.u_note_manager/same_valid_s0/I3
14.738 | 0.373 | tINS | RR | 4 | R25C90[3][B] | g_sound.u_note_manager/same_valid_s0/F
17.236 | 2.497 | tNET | RR | 1 | R61C58[3][A] | g_sound.u_note_manager/n26787_s5/I2
17.497 | 0.261 | tINS | RF | 3 | R61C58[3][A] | g_sound.u_note_manager/n26787_s5/F
17.510 | 0.014 | tNET | FF | 1 | R61C58[3][B] | g_sound.u_note_manager/n26787_s6/I3
17.884 | 0.373 | tINS | FR | 5 | R61C58[3][B] | g_sound.u_note_manager/n26787_s6/F
21.611 | 3.727 | tNET | RR | 1 | R25C92[2][B] | g_sound.u_note_manager/same_idx_r_1_s0/CE

Data Required Path:

AT | DELAY | TYPE | RF | FANOUT | LOC | NODE
17.800 | 17.800 | | | | | active clock edge time
17.800 | 0.000 | | | | | clk_sys
17.800 | 0.000 | tCL | RR | 1 | IOB117[B] | clk_ibuf/I
19.088 | 1.288 | tINS | RR | 17271 | IOB117[B] | clk_ibuf/O
21.950 | 2.862 | tNET | RR | 1 | R25C92[2][B] | g_sound.u_note_manager/same_idx_r_1_s0/CLK
21.670 | -0.280 | tSu | | 1 | R25C92[2][B] | g_sound.u_note_manager/same_idx_r_1_s0

Path Statistics:

Clock Skew | 0.000
Setup Relationship | 17.800
Logic Level | 9
Arrival Clock Path Delay | cell: 1.288, 31.042%; route: 2.862, 68.958%
Arrival Data Path Delay | cell: 2.908, 16.655%; route: 12.743, 72.984%; tC2Q: 1.809, 10.360%
Required Clock Path Delay | cell: 1.288, 31.042%; route: 2.862, 68.958%

### Path3

Path Summary:

Slack | 0.059
Data Arrival Time | 21.611
Data Required Time | 21.670
From | g_sound.u_note_manager/fifo_ax_fifo_ax_0_0_s
To | g_sound.u_note_manager/same_idx_r_2_s0
Launch Clk | clk_sys:[R]
Latch Clk | clk_sys:[R]

Data Arrival Path:

AT | DELAY | TYPE | RF | FANOUT | LOC | NODE
0.000 | 0.000 | | | | | active clock edge time
0.000 | 0.000 | | | | | clk_sys
0.000 | 0.000 | tCL | RR | 1 | IOB117[B] | clk_ibuf/I
1.288 | 1.288 | tINS | RR | 17271 | IOB117[B] | clk_ibuf/O
4.150 | 2.862 | tNET | RR | 16 | BSRAM_R56[11][A] | g_sound.u_note_manager/fifo_ax_fifo_ax_0_0_s/CLKB
5.959 | 1.809 | tC2Q | RR | 35 | BSRAM_R56[11][A] | g_sound.u_note_manager/fifo_ax_fifo_ax_0_0_s/DO[2]
8.563 | 2.604 | tNET | RR | 2 | R71C55[1][A] | g_sound.u_note_manager/n1777_s0/I1
9.069 | 0.506 | tINS | RF | 1 | R71C55[1][A] | g_sound.u_note_manager/n1777_s0/COUT
9.069 | 0.000 | tNET | FF | 2 | R71C55[1][B] | g_sound.u_note_manager/n1778_s0/CIN
9.114 | 0.045 | tINS | FR | 2 | R71C55[1][B] | g_sound.u_note_manager/n1778_s0/COUT
11.406 | 2.292 | tNET | RR | 1 | R37C70[3][B] | g_sound.u_note_manager/same_valid_s24/I3
11.875 | 0.469 | tINS | RR | 3 | R37C70[3][B] | g_sound.u_note_manager/same_valid_s24/F
13.024 | 1.149 | tNET | RR | 1 | R25C89[2][B] | g_sound.u_note_manager/same_valid_s11/I1
13.439 | 0.415 | tINS | RR | 3 | R25C89[2][B] | g_sound.u_note_manager/same_valid_s11/F
13.756 | 0.317 | tNET | RR | 1 | R24C90[2][A] | g_sound.u_note_manager/same_valid_s4/I0
14.221 | 0.465 | tINS | RR | 2 | R24C90[2][A] | g_sound.u_note_manager/same_valid_s4/F
14.365 | 0.144 | tNET | RR | 1 | R25C90[3][B] | g_sound.u_note_manager/same_valid_s0/I3
14.738 | 0.373 | tINS | RR | 4 | R25C90[3][B] | g_sound.u_note_manager/same_valid_s0/F
17.236 | 2.497 | tNET | RR | 1 | R61C58[3][A] | g_sound.u_note_manager/n26787_s5/I2
17.497 | 0.261 | tINS | RF | 3 | R61C58[3][A] | g_sound.u_note_manager/n26787_s5/F
17.510 | 0.014 | tNET | FF | 1 | R61C58[3][B] | g_sound.u_note_manager/n26787_s6/I3
17.884 | 0.373 | tINS | FR | 5 | R61C58[3][B] | g_sound.u_note_manager/n26787_s6/F
21.611 | 3.727 | tNET | RR | 1 | R25C92[0][B] | g_sound.u_note_manager/same_idx_r_2_s0/CE

Data Required Path:

AT | DELAY | TYPE | RF | FANOUT | LOC | NODE
17.800 | 17.800 | | | | | active clock edge time
17.800 | 0.000 | | | | | clk_sys
17.800 | 0.000 | tCL | RR | 1 | IOB117[B] | clk_ibuf/I
19.088 | 1.288 | tINS | RR | 17271 | IOB117[B] | clk_ibuf/O
21.950 | 2.862 | tNET | RR | 1 | R25C92[0][B] | g_sound.u_note_manager/same_idx_r_2_s0/CLK
21.670 | -0.280 | tSu | | 1 | R25C92[0][B] | g_sound.u_note_manager/same_idx_r_2_s0

Path Statistics:

Clock Skew | 0.000
Setup Relationship | 17.800
Logic Level | 9
Arrival Clock Path Delay | cell: 1.288, 31.042%; route: 2.862, 68.958%
Arrival Data Path Delay | cell: 2.908, 16.655%; route: 12.743, 72.984%; tC2Q: 1.809, 10.360%
Required Clock Path Delay | cell: 1.288, 31.042%; route: 2.862, 68.958%

### Path4

Path Summary:

Slack | 0.506
Data Arrival Time | 21.147
Data Required Time | 21.653
From | g_sound.u_note_manager/fifo_ax_fifo_ax_0_0_s
To | g_sound.u_note_manager/same_idx_r_3_s0
Launch Clk | clk_sys:[R]
Latch Clk | clk_sys:[R]

Data Arrival Path:

AT | DELAY | TYPE | RF | FANOUT | LOC | NODE
0.000 | 0.000 | | | | | active clock edge time
0.000 | 0.000 | | | | | clk_sys
0.000 | 0.000 | tCL | RR | 1 | IOB117[B] | clk_ibuf/I
1.288 | 1.288 | tINS | RR | 17271 | IOB117[B] | clk_ibuf/O
4.150 | 2.862 | tNET | RR | 16 | BSRAM_R56[11][A] | g_sound.u_note_manager/fifo_ax_fifo_ax_0_0_s/CLKB
5.959 | 1.809 | tC2Q | RR | 35 | BSRAM_R56[11][A] | g_sound.u_note_manager/fifo_ax_fifo_ax_0_0_s/DO[2]
8.563 | 2.604 | tNET | RR | 2 | R71C55[1][A] | g_sound.u_note_manager/n1777_s0/I1
9.069 | 0.506 | tINS | RF | 1 | R71C55[1][A] | g_sound.u_note_manager/n1777_s0/COUT
9.069 | 0.000 | tNET | FF | 2 | R71C55[1][B] | g_sound.u_note_manager/n1778_s0/CIN
9.114 | 0.045 | tINS | FR | 2 | R71C55[1][B] | g_sound.u_note_manager/n1778_s0/COUT
11.406 | 2.292 | tNET | RR | 1 | R37C70[3][B] | g_sound.u_note_manager/same_valid_s24/I3
11.875 | 0.469 | tINS | RR | 3 | R37C70[3][B] | g_sound.u_note_manager/same_valid_s24/F
13.024 | 1.149 | tNET | RR | 1 | R25C89[2][B] | g_sound.u_note_manager/same_valid_s11/I1
13.439 | 0.415 | tINS | RR | 3 | R25C89[2][B] | g_sound.u_note_manager/same_valid_s11/F
13.756 | 0.317 | tNET | RR | 1 | R24C90[2][A] | g_sound.u_note_manager/same_valid_s4/I0
14.221 | 0.465 | tINS | RR | 2 | R24C90[2][A] | g_sound.u_note_manager/same_valid_s4/F
14.365 | 0.144 | tNET | RR | 1 | R25C90[3][B] | g_sound.u_note_manager/same_valid_s0/I3
14.738 | 0.373 | tINS | RR | 4 | R25C90[3][B] | g_sound.u_note_manager/same_valid_s0/F
17.236 | 2.497 | tNET | RR | 1 | R61C58[3][A] | g_sound.u_note_manager/n26787_s5/I2
17.497 | 0.261 | tINS | RF | 3 | R61C58[3][A] | g_sound.u_note_manager/n26787_s5/F
17.510 | 0.014 | tNET | FF | 1 | R61C58[3][B] | g_sound.u_note_manager/n26787_s6/I3
17.884 | 0.373 | tINS | FR | 5 | R61C58[3][B] | g_sound.u_note_manager/n26787_s6/F
21.147 | 3.264 | tNET | RR | 1 | R25C90[0][A] | g_sound.u_note_manager/same_idx_r_3_s0/CE

Data Required Path:

AT | DELAY | TYPE | RF | FANOUT | LOC | NODE
17.800 | 17.800 | | | | | active clock edge time
17.800 | 0.000 | | | | | clk_sys
17.800 | 0.000 | tCL | RR | 1 | IOB117[B] | clk_ibuf/I
19.088 | 1.288 | tINS | RR | 17271 | IOB117[B] | clk_ibuf/O
21.933 | 2.845 | tNET | RR | 1 | R25C90[0][A] | g_sound.u_note_manager/same_idx_r_3_s0/CLK
21.653 | -0.280 | tSu | | 1 | R25C90[0][A] | g_sound.u_note_manager/same_idx_r_3_s0

Path Statistics:

Clock Skew | -0.017
Setup Relationship | 17.800
Logic Level | 9
Arrival Clock Path Delay | cell: 1.288, 31.042%; route: 2.862, 68.958%
Arrival Data Path Delay | cell: 2.908, 17.110%; route: 12.280, 72.247%; tC2Q: 1.809, 10.643%
Required Clock Path Delay | cell: 1.288, 31.169%; route: 2.845, 68.831%

### Path5

Path Summary:

Slack | 0.514
Data Arrival Time | 21.147
Data Required Time | 21.662
From | g_sound.u_note_manager/fifo_ax_fifo_ax_0_0_s
To | g_sound.u_note_manager/same_idx_r_4_s0
Launch Clk | clk_sys:[R]
Latch Clk | clk_sys:[R]

Data Arrival Path:

AT | DELAY | TYPE | RF | FANOUT | LOC | NODE
0.000 | 0.000 | | | | | active clock edge time
0.000 | 0.000 | | | | | clk_sys
0.000 | 0.000 | tCL | RR | 1 | IOB117[B] | clk_ibuf/I
1.288 | 1.288 | tINS | RR | 17271 | IOB117[B] | clk_ibuf/O
4.150 | 2.862 | tNET | RR | 16 | BSRAM_R56[11][A] | g_sound.u_note_manager/fifo_ax_fifo_ax_0_0_s/CLKB
5.959 | 1.809 | tC2Q | RR | 35 | BSRAM_R56[11][A] | g_sound.u_note_manager/fifo_ax_fifo_ax_0_0_s/DO[2]
8.563 | 2.604 | tNET | RR | 2 | R71C55[1][A] | g_sound.u_note_manager/n1777_s0/I1
9.069 | 0.506 | tINS | RF | 1 | R71C55[1][A] | g_sound.u_note_manager/n1777_s0/COUT
9.069 | 0.000 | tNET | FF | 2 | R71C55[1][B] | g_sound.u_note_manager/n1778_s0/CIN
9.114 | 0.045 | tINS | FR | 2 | R71C55[1][B] | g_sound.u_note_manager/n1778_s0/COUT
11.406 | 2.292 | tNET | RR | 1 | R37C70[3][B] | g_sound.u_note_manager/same_valid_s24/I3
11.875 | 0.469 | tINS | RR | 3 | R37C70[3][B] | g_sound.u_note_manager/same_valid_s24/F
13.024 | 1.149 | tNET | RR | 1 | R25C89[2][B] | g_sound.u_note_manager/same_valid_s11/I1
13.439 | 0.415 | tINS | RR | 3 | R25C89[2][B] | g_sound.u_note_manager/same_valid_s11/F
13.756 | 0.317 | tNET | RR | 1 | R24C90[2][A] | g_sound.u_note_manager/same_valid_s4/I0
14.221 | 0.465 | tINS | RR | 2 | R24C90[2][A] | g_sound.u_note_manager/same_valid_s4/F
14.365 | 0.144 | tNET | RR | 1 | R25C90[3][B] | g_sound.u_note_manager/same_valid_s0/I3
14.738 | 0.373 | tINS | RR | 4 | R25C90[3][B] | g_sound.u_note_manager/same_valid_s0/F
17.236 | 2.497 | tNET | RR | 1 | R61C58[3][A] | g_sound.u_note_manager/n26787_s5/I2
17.497 | 0.261 | tINS | RF | 3 | R61C58[3][A] | g_sound.u_note_manager/n26787_s5/F
17.510 | 0.014 | tNET | FF | 1 | R61C58[3][B] | g_sound.u_note_manager/n26787_s6/I3
17.884 | 0.373 | tINS | FR | 5 | R61C58[3][B] | g_sound.u_note_manager/n26787_s6/F
21.147 | 3.264 | tNET | RR | 1 | R25C89[2][A] | g_sound.u_note_manager/same_idx_r_4_s0/CE

Data Required Path:

AT | DELAY | TYPE | RF | FANOUT | LOC | NODE
17.800 | 17.800 | | | | | active clock edge time
17.800 | 0.000 | | | | | clk_sys
17.800 | 0.000 | tCL | RR | 1 | IOB117[B] | clk_ibuf/I
19.088 | 1.288 | tINS | RR | 17271 | IOB117[B] | clk_ibuf/O
21.942 | 2.854 | tNET | RR | 1 | R25C89[2][A] | g_sound.u_note_manager/same_idx_r_4_s0/CLK
21.662 | -0.280 | tSu | | 1 | R25C89[2][A] | g_sound.u_note_manager/same_idx_r_4_s0

Path Statistics:

Clock Skew | -0.008
Setup Relationship | 17.800
Logic Level | 9
Arrival Clock Path Delay | cell: 1.288, 31.042%; route: 2.862, 68.958%
Arrival Data Path Delay | cell: 2.908, 17.110%; route: 12.280, 72.247%; tC2Q: 1.809, 10.643%
Required Clock Path Delay | cell: 1.288, 31.105%; route: 2.854, 68.895%

#### Timing Path Constraint[2]: set_max_delay -from [get_clocks {clk_sys}] -to [get_regs {u_hdmi/u_scope/gray_launch_*_s0 u_hdmi/u_scope/full_launch_s0}] 10.000

### Path1

Path Summary:

Slack | 7.411
Data Arrival Time | 6.511
Data Required Time | 13.922
From | u_rst_sync/sync_chain_1_s0
To | u_hdmi/u_scope/full_launch_s0
Launch Clk | clk_sys:[R]
Latch Clk | clk_sys:[F]

Data Arrival Path:

AT | DELAY | TYPE | RF | FANOUT | LOC | NODE
0.000 | 0.000 | | | | | active clock edge time
0.000 | 0.000 | | | | | clk_sys
0.000 | 0.000 | tCL | RR | 1 | IOB117[B] | clk_ibuf/I
1.288 | 1.288 | tINS | RR | 17271 | IOB117[B] | clk_ibuf/O
4.142 | 2.854 | tNET | RR | 1 | R73C54[0][A] | u_rst_sync/sync_chain_1_s0/CLK
4.486 | 0.344 | tC2Q | RR | 11902 | R73C54[0][A] | u_rst_sync/sync_chain_1_s0/Q
6.511 | 2.025 | tNET | RR | 1 | R30C87[1][A] | u_hdmi/u_scope/full_launch_s0/RESET

Data Required Path:

AT | DELAY | TYPE | RF | FANOUT | LOC | NODE
10.000 | 10.000 | | | | | active clock edge time
10.000 | 0.000 | | | | | clk_sys
10.000 | 0.000 | tCL | FF | 1 | IOB117[B] | clk_ibuf/I
11.376 | 1.376 | tINS | FF | 17271 | IOB117[B] | clk_ibuf/O
14.207 | 2.831 | tNET | FF | 1 | R30C87[1][A] | u_hdmi/u_scope/full_launch_s0/CLK
13.922 | -0.286 | tSu | | 1 | R30C87[1][A] | u_hdmi/u_scope/full_launch_s0

Path Statistics:

Clock Skew | 0.066
Setup Relationship | 10.000
Logic Level | 1
Arrival Clock Path Delay | cell: 1.288, 31.105%; route: 2.854, 68.895%
Arrival Data Path Delay | cell: 0.000, 0.000%; route: 2.025, 85.470%; tC2Q: 0.344, 14.530%
Required Clock Path Delay | cell: 1.376, 32.714%; route: 2.831, 67.286%

### Path2

Path Summary:

Slack | 7.411
Data Arrival Time | 6.511
Data Required Time | 13.922
From | u_rst_sync/sync_chain_1_s0
To | u_hdmi/u_scope/gray_launch_0_s0
Launch Clk | clk_sys:[R]
Latch Clk | clk_sys:[F]

Data Arrival Path:

AT | DELAY | TYPE | RF | FANOUT | LOC | NODE
0.000 | 0.000 | | | | | active clock edge time
0.000 | 0.000 | | | | | clk_sys
0.000 | 0.000 | tCL | RR | 1 | IOB117[B] | clk_ibuf/I
1.288 | 1.288 | tINS | RR | 17271 | IOB117[B] | clk_ibuf/O
4.142 | 2.854 | tNET | RR | 1 | R73C54[0][A] | u_rst_sync/sync_chain_1_s0/CLK
4.486 | 0.344 | tC2Q | RR | 11902 | R73C54[0][A] | u_rst_sync/sync_chain_1_s0/Q
6.511 | 2.025 | tNET | RR | 1 | R30C87[1][B] | u_hdmi/u_scope/gray_launch_0_s0/RESET

Data Required Path:

AT | DELAY | TYPE | RF | FANOUT | LOC | NODE
10.000 | 10.000 | | | | | active clock edge time
10.000 | 0.000 | | | | | clk_sys
10.000 | 0.000 | tCL | FF | 1 | IOB117[B] | clk_ibuf/I
11.376 | 1.376 | tINS | FF | 17271 | IOB117[B] | clk_ibuf/O
14.207 | 2.831 | tNET | FF | 1 | R30C87[1][B] | u_hdmi/u_scope/gray_launch_0_s0/CLK
13.922 | -0.286 | tSu | | 1 | R30C87[1][B] | u_hdmi/u_scope/gray_launch_0_s0

Path Statistics:

Clock Skew | 0.066
Setup Relationship | 10.000
Logic Level | 1
Arrival Clock Path Delay | cell: 1.288, 31.105%; route: 2.854, 68.895%
Arrival Data Path Delay | cell: 0.000, 0.000%; route: 2.025, 85.470%; tC2Q: 0.344, 14.530%
Required Clock Path Delay | cell: 1.376, 32.714%; route: 2.831, 67.286%

### Path3

Path Summary:

Slack | 7.427
Data Arrival Time | 6.494
Data Required Time | 13.922
From | u_rst_sync/sync_chain_1_s0
To | u_hdmi/u_scope/gray_launch_7_s0
Launch Clk | clk_sys:[R]
Latch Clk | clk_sys:[F]

Data Arrival Path:

AT | DELAY | TYPE | RF | FANOUT | LOC | NODE
0.000 | 0.000 | | | | | active clock edge time
0.000 | 0.000 | | | | | clk_sys
0.000 | 0.000 | tCL | RR | 1 | IOB117[B] | clk_ibuf/I
1.288 | 1.288 | tINS | RR | 17271 | IOB117[B] | clk_ibuf/O
4.142 | 2.854 | tNET | RR | 1 | R73C54[0][A] | u_rst_sync/sync_chain_1_s0/CLK
4.486 | 0.344 | tC2Q | RR | 11902 | R73C54[0][A] | u_rst_sync/sync_chain_1_s0/Q
6.494 | 2.008 | tNET | RR | 1 | R30C89[0][A] | u_hdmi/u_scope/gray_launch_7_s0/RESET

Data Required Path:

AT | DELAY | TYPE | RF | FANOUT | LOC | NODE
10.000 | 10.000 | | | | | active clock edge time
10.000 | 0.000 | | | | | clk_sys
10.000 | 0.000 | tCL | FF | 1 | IOB117[B] | clk_ibuf/I
11.376 | 1.376 | tINS | FF | 17271 | IOB117[B] | clk_ibuf/O
14.207 | 2.831 | tNET | FF | 1 | R30C89[0][A] | u_hdmi/u_scope/gray_launch_7_s0/CLK
13.922 | -0.286 | tSu | | 1 | R30C89[0][A] | u_hdmi/u_scope/gray_launch_7_s0

Path Statistics:

Clock Skew | 0.066
Setup Relationship | 10.000
Logic Level | 1
Arrival Clock Path Delay | cell: 1.288, 31.105%; route: 2.854, 68.895%
Arrival Data Path Delay | cell: 0.000, 0.000%; route: 2.008, 85.366%; tC2Q: 0.344, 14.634%
Required Clock Path Delay | cell: 1.376, 32.714%; route: 2.831, 67.286%

### Path4

Path Summary:

Slack | 7.427
Data Arrival Time | 6.494
Data Required Time | 13.922
From | u_rst_sync/sync_chain_1_s0
To | u_hdmi/u_scope/gray_launch_8_s0
Launch Clk | clk_sys:[R]
Latch Clk | clk_sys:[F]

Data Arrival Path:

AT | DELAY | TYPE | RF | FANOUT | LOC | NODE
0.000 | 0.000 | | | | | active clock edge time
0.000 | 0.000 | | | | | clk_sys
0.000 | 0.000 | tCL | RR | 1 | IOB117[B] | clk_ibuf/I
1.288 | 1.288 | tINS | RR | 17271 | IOB117[B] | clk_ibuf/O
4.142 | 2.854 | tNET | RR | 1 | R73C54[0][A] | u_rst_sync/sync_chain_1_s0/CLK
4.486 | 0.344 | tC2Q | RR | 11902 | R73C54[0][A] | u_rst_sync/sync_chain_1_s0/Q
6.494 | 2.008 | tNET | RR | 1 | R30C89[0][B] | u_hdmi/u_scope/gray_launch_8_s0/RESET

Data Required Path:

AT | DELAY | TYPE | RF | FANOUT | LOC | NODE
10.000 | 10.000 | | | | | active clock edge time
10.000 | 0.000 | | | | | clk_sys
10.000 | 0.000 | tCL | FF | 1 | IOB117[B] | clk_ibuf/I
11.376 | 1.376 | tINS | FF | 17271 | IOB117[B] | clk_ibuf/O
14.207 | 2.831 | tNET | FF | 1 | R30C89[0][B] | u_hdmi/u_scope/gray_launch_8_s0/CLK
13.922 | -0.286 | tSu | | 1 | R30C89[0][B] | u_hdmi/u_scope/gray_launch_8_s0

Path Statistics:

Clock Skew | 0.066
Setup Relationship | 10.000
Logic Level | 1
Arrival Clock Path Delay | cell: 1.288, 31.105%; route: 2.854, 68.895%
Arrival Data Path Delay | cell: 0.000, 0.000%; route: 2.008, 85.366%; tC2Q: 0.344, 14.634%
Required Clock Path Delay | cell: 1.376, 32.714%; route: 2.831, 67.286%

### Path5

Path Summary:

Slack | 7.427
Data Arrival Time | 6.494
Data Required Time | 13.922
From | u_rst_sync/sync_chain_1_s0
To | u_hdmi/u_scope/gray_launch_9_s0
Launch Clk | clk_sys:[R]
Latch Clk | clk_sys:[F]

Data Arrival Path:

AT | DELAY | TYPE | RF | FANOUT | LOC | NODE
0.000 | 0.000 | | | | | active clock edge time
0.000 | 0.000 | | | | | clk_sys
0.000 | 0.000 | tCL | RR | 1 | IOB117[B] | clk_ibuf/I
1.288 | 1.288 | tINS | RR | 17271 | IOB117[B] | clk_ibuf/O
4.142 | 2.854 | tNET | RR | 1 | R73C54[0][A] | u_rst_sync/sync_chain_1_s0/CLK
4.486 | 0.344 | tC2Q | RR | 11902 | R73C54[0][A] | u_rst_sync/sync_chain_1_s0/Q
6.494 | 2.008 | tNET | RR | 1 | R30C89[1][A] | u_hdmi/u_scope/gray_launch_9_s0/RESET

Data Required Path:

AT | DELAY | TYPE | RF | FANOUT | LOC | NODE
10.000 | 10.000 | | | | | active clock edge time
10.000 | 0.000 | | | | | clk_sys
10.000 | 0.000 | tCL | FF | 1 | IOB117[B] | clk_ibuf/I
11.376 | 1.376 | tINS | FF | 17271 | IOB117[B] | clk_ibuf/O
14.207 | 2.831 | tNET | FF | 1 | R30C89[1][A] | u_hdmi/u_scope/gray_launch_9_s0/CLK
13.922 | -0.286 | tSu | | 1 | R30C89[1][A] | u_hdmi/u_scope/gray_launch_9_s0

Path Statistics:

Clock Skew | 0.066
Setup Relationship | 10.000
Logic Level | 1
Arrival Clock Path Delay | cell: 1.288, 31.105%; route: 2.854, 68.895%
Arrival Data Path Delay | cell: 0.000, 0.000%; route: 2.008, 85.366%; tC2Q: 0.344, 14.634%
Required Clock Path Delay | cell: 1.376, 32.714%; route: 2.831, 67.286%

### Hold Analysis Report

#### Report Command:report_exceptions -hold -max_paths 5 -max_common_paths 1

#### No timing exceptions to report!

### Recovery Analysis Report

#### Report Command:report_exceptions -recovery -max_paths 5 -max_common_paths 1

#### Timing Path Constraint[1]: set_max_delay -from [get_clocks {clk_sys}] -to [get_clocks {clk_sys}] 17.8

#### No timing paths to report!

#### Timing Path Constraint[2]: set_max_delay -from [get_clocks {clk_sys}] -to [get_regs {u_hdmi/u_scope/gray_launch_*_s0 u_hdmi/u_scope/full_launch_s0}] 10.000

#### No timing paths to report!

### Removal Analysis Report

#### Report Command:report_exceptions -removal -max_paths 5 -max_common_paths 1

#### No timing exceptions to report!

## Timing Constraints Report:

SDC Command Type | State | Detail Command
TC_CLOCK | Actived | create_clock -name clk_sys -period 20 -waveform {0 10} [get_ports {clk}]
TC_GENERATED_CLOCK | Actived | create_generated_clock -name serial_clk -source [get_ports {clk}] -master_clock clk_sys -divide_by 8 -multiply_by 20 [get_pins {u_hdmi/u_clk/u_pll/CLKOUT0}]
TC_GENERATED_CLOCK | Actived | create_generated_clock -name pixel_clk -source [get_ports {clk}] -master_clock clk_sys -divide_by 40 -multiply_by 20 [get_pins {u_hdmi/u_clk/u_pll/CLKOUT1}]
TC_OUTPUT_DELAY | Actived | set_output_delay -clock clk_sys -max 2.0 [get_ports {HP_BCK}]
TC_OUTPUT_DELAY | Actived | set_output_delay -clock clk_sys -max 2.0 [get_ports {HP_WS}]
TC_OUTPUT_DELAY | Actived | set_output_delay -clock clk_sys -max 2.0 [get_ports {HP_DIN}]
TC_FALSE_PATH | Actived | set_false_path -to [get_ports {PA_EN_n}]
TC_FALSE_PATH | Actived | set_false_path -to [get_ports {led_heartbeat}]
TC_FALSE_PATH | Actived | set_false_path -from [get_ports {rst_n}]
TC_MAX_DELAY | Actived | set_max_delay -from [get_clocks {clk_sys}] -to [get_clocks {clk_sys}] 17.8
TC_MAX_DELAY | Actived | set_max_delay -from [get_clocks {clk_sys}] -to [get_regs {u_hdmi/u_scope/gray_launch_*_s0 u_hdmi/u_scope/full_launch_s0}] 10.000
