hokuu1102/Gowin2026-PolySynth/evidence/merge_fix_20261013/v2/Gowin2026_tr_content.html

# Timing Messages

Report Title | Timing Analysis Report
Design File | C:\Users\cyx\Documents\ChatGPT\FPGA\fix-audit-20261013-6efd069-v2\impl\gwsynthesis\Gowin2026.vg
Physical Constraints File | C:\Users\cyx\Documents\ChatGPT\FPGA\fix-audit-20261013-6efd069-v2\constr\top.cst
Timing Constraint File | C:\Users\cyx\Documents\ChatGPT\FPGA\fix-audit-20261013-6efd069-v2\constr\top.sdc
Tool Version | V1.9.12.03 (64-bit)
Part Number | GW5AT-LV60PG484AC1/I0
Device | GW5AT-60
Device Version | B
Created Time | Tue Oct 13 10:50:01 2026
Legal Announcement | Copyright (C)2014-2026 Gowin Semiconductor Corporation. All rights reserved.

# Timing Summaries

## STA Tool Run Summary:

Setup Delay Model | Slow 0.93V 0C C1/I0
Hold Delay Model | Fast 0.975V 85C C1/I0
Numbers of Paths Analyzed | 54230
Numbers of Endpoints Analyzed | 57948
Numbers of Falling Endpoints | 28
Numbers of Setup Violated Endpoints | 0
Numbers of Hold Violated Endpoints | 0

## Clock Summary:

NO. | Clock Name | Type | Period | Frequency(MHz) | Rise | Fall | Source | Master | Objects
1 | clk_sys | Base | 20.000 | 50.000 | 0.000 | 10.000 | | | clk
2 | serial_clk | Generated | 8.000 | 125.000 | 0.000 | 4.000 | clk | clk_sys | u_hdmi/u_clk/u_pll/CLKOUT0
3 | pixel_clk | Generated | 40.000 | 25.000 | 0.000 | 20.000 | clk | clk_sys | u_hdmi/u_clk/u_pll/CLKOUT1

## Max Frequency Summary:

NO. | Clock Name | Constraint | Actual Fmax | Logic Level | Entity
1 | clk_sys | 50.000(MHz) | 56.369(MHz) | 11 | TOP
2 | serial_clk | 125.000(MHz) | 364.597(MHz) | 2 | TOP
3 | pixel_clk | 25.000(MHz) | 41.374(MHz) | 12 | TOP

## Total Negative Slack Summary:

Clock Name | Analysis Type | Endpoints TNS | Number of Endpoints
clk_sys | Setup | 0.000 | 0
clk_sys | Hold | 0.000 | 0
serial_clk | Setup | 0.000 | 0
serial_clk | Hold | 0.000 | 0
pixel_clk | Setup | 0.000 | 0
pixel_clk | Hold | 0.000 | 0

# Timing Details

## Path Slacks Table:

### Setup Paths Table

#### Report Command:report_timing -setup -max_paths 25 -max_common_paths 1

Path Number | Path Slack | From Node | To Node | From Clock | To Clock | Relation | Clock Skew | Data Delay
1 | 0.060 | g_sound.u_pos_probe/rem_5_s0/Q | g_sound.u_pos_probe/rem_4_s0/D | clk_sys:[R] | clk_sys:[R] | 17.800 | 0.017 | 17.666
2 | 0.118 | g_sound.u_pos_probe/rem_5_s0/Q | g_sound.u_pos_probe/rem_3_s0/D | clk_sys:[R] | clk_sys:[R] | 17.800 | 0.008 | 17.616
3 | 0.182 | g_sound.u_pos_probe/rem_5_s0/Q | g_sound.u_pos_probe/rem_2_s0/D | clk_sys:[R] | clk_sys:[R] | 17.800 | 0.008 | 17.552
4 | 0.219 | g_sound.u_adc_farm/u_scan0/sample_channel_0_s0/Q | g_sound.u_calib0/n909_s/A[3] | clk_sys:[R] | clk_sys:[R] | 17.800 | -0.008 | 14.336
5 | 0.245 | g_sound.u_fader_gear/gear_o_0_s0/Q | g_sound.u_vibrato_lfo/rate_inc_q_22_s0/D | clk_sys:[R] | clk_sys:[R] | 17.800 | -0.008 | 17.506
6 | 0.343 | g_sound.u_adc_farm/u_scan0/sample_channel_2_s0/Q | g_sound.u_autotare/still_cnt_still_cnt_RAMREG_7_G[2]_s0/D | clk_sys:[R] | clk_sys:[R] | 17.800 | 0.008 | 17.391
7 | 0.364 | g_sound.u_adc_farm/u_scan0/sample_channel_0_s0/Q | g_sound.u_calib0/n909_s/A[2] | clk_sys:[R] | clk_sys:[R] | 17.800 | -0.008 | 14.043
8 | 0.394 | g_sound.u_fader_gear/gear_o_0_s0/Q | g_sound.u_vibrato_lfo/rate_inc_q_27_s0/D | clk_sys:[R] | clk_sys:[R] | 17.800 | 0.000 | 17.348
9 | 0.403 | g_sound.u_fader_gear/gear_o_0_s0/Q | g_sound.u_vibrato_lfo/rate_inc_q_28_s0/D | clk_sys:[R] | clk_sys:[R] | 17.800 | -0.008 | 17.348
10 | 0.455 | g_sound.u_adc_farm/shadow_hold_shadow_hold_RAMREG_2_G[0]_s1/Q | g_sound.u_calib1/n909_s/A[0] | clk_sys:[R] | clk_sys:[R] | 17.800 | -0.008 | 13.888
11 | 0.480 | g_sound.u_adc_farm/u_scan0/sample_channel_0_s0/Q | g_sound.u_calib0/n909_s/A[0] | clk_sys:[R] | clk_sys:[R] | 17.800 | -0.008 | 13.869
12 | 0.516 | g_sound.u_fader_gear/gear_o_0_s0/Q | g_sound.u_vibrato_lfo/rate_inc_q_23_s0/D | clk_sys:[R] | clk_sys:[R] | 17.800 | 0.008 | 17.218
13 | 0.522 | g_sound.u_adc_farm/u_scan0/sample_channel_2_s0/Q | g_sound.u_autotare/still_cnt_still_cnt_RAMREG_7_G[1]_s0/D | clk_sys:[R] | clk_sys:[R] | 17.800 | 0.000 | 17.220
14 | 0.551 | g_sound.u_adc_farm/u_scan0/sample_channel_2_s0/Q | g_sound.u_autotare/still_cnt_still_cnt_RAMREG_7_G[0]_s0/D | clk_sys:[R] | clk_sys:[R] | 17.800 | -0.008 | 17.200
15 | 0.554 | g_sound.u_adc_farm/u_scan0/sample_channel_2_s0/Q | g_sound.u_autotare/still_cnt_still_cnt_RAMREG_4_G[2]_s0/D | clk_sys:[R] | clk_sys:[R] | 17.800 | 0.008 | 17.180
16 | 0.563 | g_sound.u_adc_farm/u_scan0/sample_channel_2_s0/Q | g_sound.u_autotare/still_cnt_still_cnt_RAMREG_4_G[1]_s0/D | clk_sys:[R] | clk_sys:[R] | 17.800 | 0.000 | 17.180
17 | 0.589 | g_sound.u_adc_farm/u_scan0/sample_channel_0_s0/Q | g_sound.u_calib0/n909_s/A[4] | clk_sys:[R] | clk_sys:[R] | 17.800 | -0.008 | 13.925
18 | 0.624 | g_sound.u_adc_farm/shadow_hold_shadow_hold_RAMREG_2_G[0]_s1/Q | g_sound.u_calib1/n909_s/A[4] | clk_sys:[R] | clk_sys:[R] | 17.800 | -0.008 | 13.890
19 | 0.651 | g_sound.u_adc_farm/u_scan0/sample_channel_0_s0/Q | g_sound.u_calib0/n909_s/A[6] | clk_sys:[R] | clk_sys:[R] | 17.800 | -0.008 | 13.904
20 | 0.679 | g_sound.u_pos_probe/rem_5_s0/Q | g_sound.u_pos_probe/rem_11_s0/D | clk_sys:[R] | clk_sys:[R] | 17.800 | 0.008 | 17.061
21 | 0.684 | g_sound.u_adc_farm/u_scan0/sample_channel_0_s0/Q | g_sound.u_calib0/n909_s/A[1] | clk_sys:[R] | clk_sys:[R] | 17.800 | -0.008 | 13.745
22 | 0.692 | g_sound.u_adc_farm/shadow_hold_shadow_hold_RAMREG_2_G[0]_s1/Q | g_sound.u_calib1/n909_s/A[5] | clk_sys:[R] | clk_sys:[R] | 17.800 | -0.008 | 13.867
23 | 0.694 | g_sound.u_pos_probe/rem_5_s0/Q | g_sound.u_pos_probe/rem_9_s0/D | clk_sys:[R] | clk_sys:[R] | 17.800 | 0.008 | 17.040
24 | 0.698 | g_sound.u_fader_gear/gear_o_0_s0/Q | g_sound.u_vibrato_lfo/rate_inc_q_1_s0/CE | clk_sys:[R] | clk_sys:[R] | 17.800 | -0.008 | 16.831
25 | 0.702 | g_sound.u_adc_farm/u_scan0/sample_channel_0_s0/Q | g_sound.u_calib0/n909_s/A[5] | clk_sys:[R] | clk_sys:[R] | 17.800 | -0.008 | 13.857

### Hold Paths Table

#### Report Command:report_timing -hold -max_paths 25 -max_common_paths 1

Path Number | Path Slack | From Node | To Node | From Clock | To Clock | Relation | Clock Skew | Data Delay
1 | 0.180 | g_sound.u_looper/rd_ptr_r_9_s0/Q | g_sound.u_looper/ep_mem_ep_mem_0_2_s/ADB[12] | clk_sys:[R] | clk_sys:[R] | 0.000 | -0.177 | 0.389
2 | 0.214 | g_sound.u_envelope_bank/env_active_o_19_s0/Q | g_sound.u_note_manager/env_active_r_19_s0/D | clk_sys:[R] | clk_sys:[R] | 0.000 | -0.177 | 0.403
3 | 0.225 | u_evt_uart_rx/evt_data_o_31_s0/Q | u_evt_buf/mem_mem_0_1_s/DI[8] | clk_sys:[R] | clk_sys:[R] | 0.000 | 0.000 | 0.258
4 | 0.232 | u_hdmi/u_green/symbol_9_s0/Q | u_hdmi/u_serializer/lanes[1].u_oser/D9 | pixel_clk:[R] | pixel_clk:[R] | 0.000 | 0.007 | 0.300
5 | 0.247 | u_led_indicator/beat_t_18_s3/Q | u_led_indicator/beat_t_18_s3/D | clk_sys:[R] | clk_sys:[R] | 0.000 | 0.000 | 0.270
6 | 0.247 | u_led_indicator/beat_t_22_s5/Q | u_led_indicator/beat_t_22_s5/D | clk_sys:[R] | clk_sys:[R] | 0.000 | 0.000 | 0.270
7 | 0.247 | u_led_indicator/beat_t_11_s1/Q | u_led_indicator/beat_t_11_s1/D | clk_sys:[R] | clk_sys:[R] | 0.000 | 0.000 | 0.270
8 | 0.247 | u_led_indicator/beat_t_14_s1/Q | u_led_indicator/beat_t_14_s1/D | clk_sys:[R] | clk_sys:[R] | 0.000 | 0.000 | 0.270
9 | 0.247 | u_led_indicator/beat_t_12_s0/Q | u_led_indicator/beat_t_12_s0/D | clk_sys:[R] | clk_sys:[R] | 0.000 | 0.000 | 0.270
10 | 0.247 | u_ws2812/bit_i_2_s1/Q | u_ws2812/bit_i_2_s1/D | clk_sys:[R] | clk_sys:[R] | 0.000 | 0.000 | 0.270
11 | 0.247 | u_ws2812/rst_t_0_s0/Q | u_ws2812/rst_t_0_s0/D | clk_sys:[R] | clk_sys:[R] | 0.000 | 0.000 | 0.270
12 | 0.247 | u_ws2812/rst_t_3_s0/Q | u_ws2812/rst_t_3_s0/D | clk_sys:[R] | clk_sys:[R] | 0.000 | 0.000 | 0.270
13 | 0.247 | u_ws2812/rst_t_10_s0/Q | u_ws2812/rst_t_10_s0/D | clk_sys:[R] | clk_sys:[R] | 0.000 | 0.000 | 0.270
14 | 0.247 | u_led_bank/u_driver/rec_cnt_0_s0/Q | u_led_bank/u_driver/rec_cnt_0_s0/D | clk_sys:[R] | clk_sys:[R] | 0.000 | 0.000 | 0.270
15 | 0.247 | u_led_bank/display_count_5_s1/Q | u_led_bank/display_count_5_s1/D | clk_sys:[R] | clk_sys:[R] | 0.000 | 0.000 | 0.270
16 | 0.247 | u_led_bank/display_count_9_s1/Q | u_led_bank/display_count_9_s1/D | clk_sys:[R] | clk_sys:[R] | 0.000 | 0.000 | 0.270
17 | 0.247 | u_led_bank/display_count_12_s1/Q | u_led_bank/display_count_12_s1/D | clk_sys:[R] | clk_sys:[R] | 0.000 | 0.000 | 0.270
18 | 0.247 | u_i2s_tx_ext/ch_s0/Q | u_i2s_tx_ext/ch_s0/D | clk_sys:[R] | clk_sys:[R] | 0.000 | 0.000 | 0.270
19 | 0.247 | u_i2s_tx/HP_BCK_s1/Q | u_i2s_tx/HP_BCK_s1/D | clk_sys:[R] | clk_sys:[R] | 0.000 | 0.000 | 0.270
20 | 0.247 | u_i2s_tx/ch_s0/Q | u_i2s_tx/ch_s0/D | clk_sys:[R] | clk_sys:[R] | 0.000 | 0.000 | 0.270
21 | 0.247 | g_sound.u_tdm_render_mixer/valid_d_1_s0/Q | g_sound.u_tdm_render_mixer/valid_d_2_s0/D | clk_sys:[R] | clk_sys:[R] | 0.000 | 0.000 | 0.200
22 | 0.247 | g_sound.u_tdm_render_mixer/valid_d_2_s0/Q | g_sound.u_tdm_render_mixer/valid_d_3_s0/D | clk_sys:[R] | clk_sys:[R] | 0.000 | 0.000 | 0.200
23 | 0.247 | g_sound.u_perc_env_bank/gen_perc[4].level_r_5_s0/Q | g_sound.u_perc_env_bank/gen_perc[4].level_r_5_s0/D | clk_sys:[R] | clk_sys:[R] | 0.000 | 0.000 | 0.270
24 | 0.247 | g_sound.u_perc_env_bank/gen_perc[4].level_r_6_s0/Q | g_sound.u_perc_env_bank/gen_perc[4].level_r_6_s0/D | clk_sys:[R] | clk_sys:[R] | 0.000 | 0.000 | 0.270
25 | 0.247 | g_sound.u_perc_env_bank/gen_perc[3].level_r_3_s0/Q | g_sound.u_perc_env_bank/gen_perc[3].level_r_3_s0/D | clk_sys:[R] | clk_sys:[R] | 0.000 | 0.000 | 0.270

### Recovery Paths Table

#### Report Command:report_timing -recovery -max_paths 25 -max_common_paths 1

Path Number | Path Slack | From Node | To Node | From Clock | To Clock | Relation | Clock Skew | Data Delay
1 | 1.169 | u_hdmi/u_serializer/lanes[0].lane_reset_s1/Q | u_hdmi/u_serializer/lanes[0].u_oser/RESET | serial_clk:[R] | serial_clk:[F] | 4.000 | 1.898 | 0.798
2 | 1.196 | u_hdmi/u_serializer/lanes[3].lane_reset_s1/Q | u_hdmi/u_serializer/lanes[3].u_oser/RESET | serial_clk:[R] | serial_clk:[F] | 4.000 | 1.898 | 0.771
3 | 1.334 | u_hdmi/u_serializer/lanes[2].lane_reset_s1/Q | u_hdmi/u_serializer/lanes[2].u_oser/RESET | serial_clk:[R] | serial_clk:[F] | 4.000 | 1.898 | 0.632
4 | 1.334 | u_hdmi/u_serializer/lanes[1].lane_reset_s1/Q | u_hdmi/u_serializer/lanes[1].u_oser/RESET | serial_clk:[R] | serial_clk:[F] | 4.000 | 1.898 | 0.632
5 | 5.167 | u_hdmi/u_serializer/lanes[0].lane_reset_s1/Q | u_hdmi/u_serializer/lanes[0].u_oser/RESET | serial_clk:[R] | serial_clk:[R] | 8.000 | 1.898 | 0.798
6 | 5.194 | u_hdmi/u_serializer/lanes[3].lane_reset_s1/Q | u_hdmi/u_serializer/lanes[3].u_oser/RESET | serial_clk:[R] | serial_clk:[R] | 8.000 | 1.898 | 0.771
7 | 5.332 | u_hdmi/u_serializer/lanes[1].lane_reset_s1/Q | u_hdmi/u_serializer/lanes[1].u_oser/RESET | serial_clk:[R] | serial_clk:[R] | 8.000 | 1.898 | 0.632
8 | 5.332 | u_hdmi/u_serializer/lanes[2].lane_reset_s1/Q | u_hdmi/u_serializer/lanes[2].u_oser/RESET | serial_clk:[R] | serial_clk:[R] | 8.000 | 1.898 | 0.632
9 | 7.013 | u_hdmi/u_serializer/lanes[0].lane_reset_s1/Q | u_hdmi/u_serializer/lanes[0].u_oser/RESET | serial_clk:[R] | pixel_clk:[R] | 8.000 | 0.017 | 0.798
10 | 7.040 | u_hdmi/u_serializer/lanes[3].lane_reset_s1/Q | u_hdmi/u_serializer/lanes[3].u_oser/RESET | serial_clk:[R] | pixel_clk:[R] | 8.000 | 0.017 | 0.771
11 | 7.178 | u_hdmi/u_serializer/lanes[1].lane_reset_s1/Q | u_hdmi/u_serializer/lanes[1].u_oser/RESET | serial_clk:[R] | pixel_clk:[R] | 8.000 | 0.017 | 0.632
12 | 7.178 | u_hdmi/u_serializer/lanes[2].lane_reset_s1/Q | u_hdmi/u_serializer/lanes[2].u_oser/RESET | serial_clk:[R] | pixel_clk:[R] | 8.000 | 0.017 | 0.632

### Removal Paths Table

#### Report Command:report_timing -removal -max_paths 25 -max_common_paths 1

Path Number | Path Slack | From Node | To Node | From Clock | To Clock | Relation | Clock Skew | Data Delay
1 | 0.123 | u_hdmi/u_serializer/lanes[3].lane_reset_s1/Q | u_hdmi/u_serializer/lanes[3].u_oser/RESET | serial_clk:[R] | pixel_clk:[R] | 0.000 | 0.007 | 0.288
2 | 0.136 | u_hdmi/u_serializer/lanes[2].lane_reset_s1/Q | u_hdmi/u_serializer/lanes[2].u_oser/RESET | serial_clk:[R] | pixel_clk:[R] | 0.000 | 0.007 | 0.301
3 | 0.136 | u_hdmi/u_serializer/lanes[1].lane_reset_s1/Q | u_hdmi/u_serializer/lanes[1].u_oser/RESET | serial_clk:[R] | pixel_clk:[R] | 0.000 | 0.007 | 0.301
4 | 0.136 | u_hdmi/u_serializer/lanes[0].lane_reset_s1/Q | u_hdmi/u_serializer/lanes[0].u_oser/RESET | serial_clk:[R] | pixel_clk:[R] | 0.000 | 0.007 | 0.301
5 | 0.760 | u_hdmi/u_serializer/lanes[3].lane_reset_s1/Q | u_hdmi/u_serializer/lanes[3].u_oser/RESET | serial_clk:[R] | serial_clk:[R] | 0.000 | 0.609 | 0.288
6 | 0.773 | u_hdmi/u_serializer/lanes[0].lane_reset_s1/Q | u_hdmi/u_serializer/lanes[0].u_oser/RESET | serial_clk:[R] | serial_clk:[R] | 0.000 | 0.609 | 0.301
7 | 0.773 | u_hdmi/u_serializer/lanes[1].lane_reset_s1/Q | u_hdmi/u_serializer/lanes[1].u_oser/RESET | serial_clk:[R] | serial_clk:[R] | 0.000 | 0.609 | 0.301
8 | 0.773 | u_hdmi/u_serializer/lanes[2].lane_reset_s1/Q | u_hdmi/u_serializer/lanes[2].u_oser/RESET | serial_clk:[R] | serial_clk:[R] | 0.000 | 0.609 | 0.301
9 | 4.761 | u_hdmi/u_serializer/lanes[3].lane_reset_s1/Q | u_hdmi/u_serializer/lanes[3].u_oser/RESET | serial_clk:[R] | serial_clk:[F] | -4.000 | 0.609 | 0.288
10 | 4.775 | u_hdmi/u_serializer/lanes[0].lane_reset_s1/Q | u_hdmi/u_serializer/lanes[0].u_oser/RESET | serial_clk:[R] | serial_clk:[F] | -4.000 | 0.609 | 0.301
11 | 4.775 | u_hdmi/u_serializer/lanes[1].lane_reset_s1/Q | u_hdmi/u_serializer/lanes[1].u_oser/RESET | serial_clk:[R] | serial_clk:[F] | -4.000 | 0.609 | 0.301
12 | 4.775 | u_hdmi/u_serializer/lanes[2].lane_reset_s1/Q | u_hdmi/u_serializer/lanes[2].u_oser/RESET | serial_clk:[R] | serial_clk:[F] | -4.000 | 0.609 | 0.301

## Minimum Pulse Width Table:

Number | Slack | Actual Width | Required Width | Type | Clock | Objects

#### Report Command:report_min_pulse_width -nworst 10 -detail

1 | 0.542 | 0.767 | 0.225 | Low Pulse Width | serial_clk | u_hdmi/rstn_ser_2_s0
2 | 0.542 | 0.767 | 0.225 | Low Pulse Width | serial_clk | u_hdmi/u_serializer/lanes[1].lane_reset_s0
3 | 0.542 | 0.767 | 0.225 | Low Pulse Width | serial_clk | u_hdmi/u_serializer/lanes[2].lane_reset_s0
4 | 0.542 | 0.767 | 0.225 | Low Pulse Width | serial_clk | u_hdmi/u_serializer/lanes[3].lane_reset_s0
5 | 0.542 | 0.767 | 0.225 | Low Pulse Width | serial_clk | u_hdmi/u_serializer/lanes[0].lane_reset_s0
6 | 0.542 | 0.767 | 0.225 | Low Pulse Width | serial_clk | u_hdmi/u_serializer/lanes[0].lane_reset_s1
7 | 0.542 | 0.767 | 0.225 | Low Pulse Width | serial_clk | u_hdmi/u_serializer/lanes[3].lane_reset_s1
8 | 0.542 | 0.767 | 0.225 | Low Pulse Width | serial_clk | u_hdmi/u_serializer/lanes[2].lane_reset_s1
9 | 0.542 | 0.767 | 0.225 | Low Pulse Width | serial_clk | u_hdmi/u_serializer/lanes[1].lane_reset_s1
10 | 0.544 | 0.769 | 0.225 | High Pulse Width | serial_clk | u_hdmi/rstn_ser_2_s0

## Timing Report By Analysis Type:

### Setup Analysis Report

#### Report Command:report_timing -setup -max_paths 25 -max_common_paths 1

### Path1

Path Summary:

Slack | 0.060
Data Arrival Time | 21.816
Data Required Time | 21.876
From | g_sound.u_pos_probe/rem_5_s0
To | g_sound.u_pos_probe/rem_4_s0
Launch Clk | clk_sys:[R]
Latch Clk | clk_sys:[R]

Data Arrival Path:

AT | DELAY | TYPE | RF | FANOUT | LOC | NODE
0.000 | 0.000 | | | | | active clock edge time
0.000 | 0.000 | | | | | clk_sys
0.000 | 0.000 | tCL | RR | 1 | IOB117[B] | clk_ibuf/I
1.288 | 1.288 | tINS | RR | 18017 | IOB117[B] | clk_ibuf/O
4.150 | 2.862 | tNET | RR | 1 | R18C112[0][B] | g_sound.u_pos_probe/rem_5_s0/CLK
4.495 | 0.344 | tC2Q | RR | 22 | R18C112[0][B] | g_sound.u_pos_probe/rem_5_s0/Q
7.929 | 3.435 | tNET | RR | 1 | R3C146[2][A] | g_sound.u_pos_probe/cur_digit_0_s6/I3
8.403 | 0.474 | tINS | RR | 1 | R3C146[2][A] | g_sound.u_pos_probe/cur_digit_0_s6/F
8.405 | 0.002 | tNET | RR | 1 | R3C146[3][A] | g_sound.u_pos_probe/cur_digit_0_s4/I1
8.779 | 0.373 | tINS | RR | 1 | R3C146[3][A] | g_sound.u_pos_probe/cur_digit_0_s4/F
9.638 | 0.859 | tNET | RR | 1 | R3C127[1][B] | g_sound.u_pos_probe/cur_digit_0_s2/I1
10.053 | 0.415 | tINS | RR | 1 | R3C127[1][B] | g_sound.u_pos_probe/cur_digit_0_s2/F
10.472 | 0.418 | tNET | RR | 1 | R6C125[2][B] | g_sound.u_pos_probe/cur_digit_0_s1/I0
10.708 | 0.236 | tINS | RR | 2 | R6C125[2][B] | g_sound.u_pos_probe/cur_digit_0_s1/F
12.934 | 2.226 | tNET | RR | 24 | DSP_R28[7][B] | g_sound.u_pos_probe/cur_x100_0_s/A[0]
16.731 | 3.797 | tINS | RF | 1 | DSP_R28[7][B] | g_sound.u_pos_probe/cur_x100_0_s/DOUT[0]
17.547 | 0.816 | tNET | FF | 2 | R20C104[0][A] | g_sound.u_pos_probe/n275_s/I1
17.990 | 0.443 | tINS | FR | 1 | R20C104[0][A] | g_sound.u_pos_probe/n275_s/COUT
17.990 | 0.000 | tNET | RR | 2 | R20C104[0][B] | g_sound.u_pos_probe/n274_s/CIN
18.035 | 0.045 | tINS | RR | 1 | R20C104[0][B] | g_sound.u_pos_probe/n274_s/COUT
18.035 | 0.000 | tNET | RR | 2 | R20C104[1][A] | g_sound.u_pos_probe/n273_s/CIN
18.080 | 0.045 | tINS | RR | 1 | R20C104[1][A] | g_sound.u_pos_probe/n273_s/COUT
18.080 | 0.000 | tNET | RR | 2 | R20C104[1][B] | g_sound.u_pos_probe/n272_s/CIN
18.125 | 0.045 | tINS | RR | 1 | R20C104[1][B] | g_sound.u_pos_probe/n272_s/COUT
18.125 | 0.000 | tNET | RR | 2 | R20C104[2][A] | g_sound.u_pos_probe/n271_s/CIN
18.344 | 0.219 | tINS | RR | 1 | R20C104[2][A] | g_sound.u_pos_probe/n271_s/SUM
18.689 | 0.344 | tNET | RR | 1 | R20C108[3][B] | g_sound.u_pos_probe/n193_s3/I1
19.136 | 0.448 | tINS | RR | 1 | R20C108[3][B] | g_sound.u_pos_probe/n193_s3/F
19.504 | 0.368 | tNET | RR | 1 | R18C108[0][B] | g_sound.u_pos_probe/n193_s1/I3
19.741 | 0.236 | tINS | RR | 1 | R18C108[0][B] | g_sound.u_pos_probe/n193_s1/F
21.401 | 1.660 | tNET | RR | 1 | R4C130[0][B] | g_sound.u_pos_probe/n193_s0/I0
21.816 | 0.415 | tINS | RR | 1 | R4C130[0][B] | g_sound.u_pos_probe/n193_s0/F
21.816 | 0.000 | tNET | RR | 1 | R4C130[0][B] | g_sound.u_pos_probe/rem_4_s0/D

Data Required Path:

AT | DELAY | TYPE | RF | FANOUT | LOC | NODE
17.800 | 17.800 | | | | | active clock edge time
17.800 | 0.000 | | | | | clk_sys
17.800 | 0.000 | tCL | RR | 1 | IOB117[B] | clk_ibuf/I
19.088 | 1.288 | tINS | RR | 18017 | IOB117[B] | clk_ibuf/O
21.933 | 2.845 | tNET | RR | 1 | R4C130[0][B] | g_sound.u_pos_probe/rem_4_s0/CLK
21.876 | -0.057 | tSu | | 1 | R4C130[0][B] | g_sound.u_pos_probe/rem_4_s0

Path Statistics:

Clock Skew | -0.017
Setup Relationship | 17.800
Logic Level | 11
Arrival Clock Path Delay | cell: 1.288, 31.042%; route: 2.862, 68.958%
Arrival Data Path Delay | cell: 7.192, 40.712%; route: 10.129, 57.339%; tC2Q: 0.344, 1.949%
Required Clock Path Delay | cell: 1.288, 31.169%; route: 2.845, 68.831%

### Path2

Path Summary:

Slack | 0.118
Data Arrival Time | 21.767
Data Required Time | 21.885
From | g_sound.u_pos_probe/rem_5_s0
To | g_sound.u_pos_probe/rem_3_s0
Launch Clk | clk_sys:[R]
Latch Clk | clk_sys:[R]

Data Arrival Path:

AT | DELAY | TYPE | RF | FANOUT | LOC | NODE
0.000 | 0.000 | | | | | active clock edge time
0.000 | 0.000 | | | | | clk_sys
0.000 | 0.000 | tCL | RR | 1 | IOB117[B] | clk_ibuf/I
1.288 | 1.288 | tINS | RR | 18017 | IOB117[B] | clk_ibuf/O
4.150 | 2.862 | tNET | RR | 1 | R18C112[0][B] | g_sound.u_pos_probe/rem_5_s0/CLK
4.495 | 0.344 | tC2Q | RR | 22 | R18C112[0][B] | g_sound.u_pos_probe/rem_5_s0/Q
7.929 | 3.435 | tNET | RR | 1 | R3C146[2][A] | g_sound.u_pos_probe/cur_digit_0_s6/I3
8.403 | 0.474 | tINS | RR | 1 | R3C146[2][A] | g_sound.u_pos_probe/cur_digit_0_s6/F
8.405 | 0.002 | tNET | RR | 1 | R3C146[3][A] | g_sound.u_pos_probe/cur_digit_0_s4/I1
8.779 | 0.373 | tINS | RR | 1 | R3C146[3][A] | g_sound.u_pos_probe/cur_digit_0_s4/F
9.638 | 0.859 | tNET | RR | 1 | R3C127[1][B] | g_sound.u_pos_probe/cur_digit_0_s2/I1
10.053 | 0.415 | tINS | RR | 1 | R3C127[1][B] | g_sound.u_pos_probe/cur_digit_0_s2/F
10.472 | 0.418 | tNET | RR | 1 | R6C125[2][B] | g_sound.u_pos_probe/cur_digit_0_s1/I0
10.708 | 0.236 | tINS | RR | 2 | R6C125[2][B] | g_sound.u_pos_probe/cur_digit_0_s1/F
12.934 | 2.226 | tNET | RR | 24 | DSP_R28[7][B] | g_sound.u_pos_probe/cur_x100_0_s/A[0]
16.731 | 3.797 | tINS | RF | 1 | DSP_R28[7][B] | g_sound.u_pos_probe/cur_x100_0_s/DOUT[0]
17.547 | 0.816 | tNET | FF | 2 | R20C104[0][A] | g_sound.u_pos_probe/n275_s/I1
17.990 | 0.443 | tINS | FR | 1 | R20C104[0][A] | g_sound.u_pos_probe/n275_s/COUT
17.990 | 0.000 | tNET | RR | 2 | R20C104[0][B] | g_sound.u_pos_probe/n274_s/CIN
18.035 | 0.045 | tINS | RR | 1 | R20C104[0][B] | g_sound.u_pos_probe/n274_s/COUT
18.035 | 0.000 | tNET | RR | 2 | R20C104[1][A] | g_sound.u_pos_probe/n273_s/CIN
18.080 | 0.045 | tINS | RR | 1 | R20C104[1][A] | g_sound.u_pos_probe/n273_s/COUT
18.080 | 0.000 | tNET | RR | 2 | R20C104[1][B] | g_sound.u_pos_probe/n272_s/CIN
18.347 | 0.267 | tINS | RR | 1 | R20C104[1][B] | g_sound.u_pos_probe/n272_s/SUM
18.641 | 0.295 | tNET | RR | 1 | R20C106[3][A] | g_sound.u_pos_probe/n194_s3/I1
19.015 | 0.373 | tINS | RR | 1 | R20C106[3][A] | g_sound.u_pos_probe/n194_s3/F
19.432 | 0.417 | tNET | RR | 1 | R17C106[2][A] | g_sound.u_pos_probe/n194_s1/I3
19.669 | 0.236 | tINS | RR | 1 | R17C106[2][A] | g_sound.u_pos_probe/n194_s1/F
21.352 | 1.683 | tNET | RR | 1 | R9C141[1][B] | g_sound.u_pos_probe/n194_s0/I0
21.767 | 0.415 | tINS | RR | 1 | R9C141[1][B] | g_sound.u_pos_probe/n194_s0/F
21.767 | 0.000 | tNET | RR | 1 | R9C141[1][B] | g_sound.u_pos_probe/rem_3_s0/D

Data Required Path:

AT | DELAY | TYPE | RF | FANOUT | LOC | NODE
17.800 | 17.800 | | | | | active clock edge time
17.800 | 0.000 | | | | | clk_sys
17.800 | 0.000 | tCL | RR | 1 | IOB117[B] | clk_ibuf/I
19.088 | 1.288 | tINS | RR | 18017 | IOB117[B] | clk_ibuf/O
21.942 | 2.854 | tNET | RR | 1 | R9C141[1][B] | g_sound.u_pos_probe/rem_3_s0/CLK
21.885 | -0.057 | tSu | | 1 | R9C141[1][B] | g_sound.u_pos_probe/rem_3_s0

Path Statistics:

Clock Skew | -0.008
Setup Relationship | 17.800
Logic Level | 11
Arrival Clock Path Delay | cell: 1.288, 31.042%; route: 2.862, 68.958%
Arrival Data Path Delay | cell: 7.120, 40.418%; route: 10.152, 57.628%; tC2Q: 0.344, 1.954%
Required Clock Path Delay | cell: 1.288, 31.105%; route: 2.854, 68.895%
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
