hokuu1102/Gowin2026-PolySynth/sim/evidence/rightboard-vibrato-fix-20261008/timing-rightadc-a3.html

# Timing Messages

Report Title | Timing Analysis Report
Design File | C:\Users\hokuu\Desktop\FPGA\FPGA2026\build\rightadc-probe\impl\gwsynthesis\Gowin2026.vg
Physical Constraints File | C:\Users\hokuu\Desktop\FPGA\FPGA2026\build\rightadc-probe\constr\top.cst
Timing Constraint File | C:\Users\hokuu\Desktop\FPGA\FPGA2026\build\rightadc-probe\constr\top.sdc
Tool Version | V1.9.12.03 (64-bit)
Part Number | GW5AT-LV60PG484AC1/I0
Device | GW5AT-60
Device Version | B
Created Time | Fri Oct 9 01:55:05 2026
Legal Announcement | Copyright (C)2014-2026 Gowin Semiconductor Corporation. All rights reserved.

# Timing Summaries

## STA Tool Run Summary:

Setup Delay Model | Slow 0.93V 0C C1/I0
Hold Delay Model | Fast 0.975V 85C C1/I0
Numbers of Paths Analyzed | 51334
Numbers of Endpoints Analyzed | 53479
Numbers of Falling Endpoints | 26
Numbers of Setup Violated Endpoints | 0
Numbers of Hold Violated Endpoints | 0

## Clock Summary:

NO. | Clock Name | Type | Period | Frequency(MHz) | Rise | Fall | Source | Master | Objects
1 | clk_sys | Base | 20.000 | 50.000 | 0.000 | 10.000 | | | clk
2 | serial_clk | Generated | 8.000 | 125.000 | 0.000 | 4.000 | clk | clk_sys | u_hdmi/u_clk/u_pll/CLKOUT0
3 | pixel_clk | Generated | 40.000 | 25.000 | 0.000 | 20.000 | clk | clk_sys | u_hdmi/u_clk/u_pll/CLKOUT1

## Max Frequency Summary:

NO. | Clock Name | Constraint | Actual Fmax | Logic Level | Entity
1 | clk_sys | 50.000(MHz) | 57.016(MHz) | 10 | TOP
2 | pixel_clk | 25.000(MHz) | 122.049(MHz) | 11 | TOP

#### No timing paths to get frequency of serial_clk!

## Total Negative Slack Summary:

Clock Name | Analysis Type | Endpoints TNS | Number of Endpoints
clk_sys | Setup | 0.000 | 0
clk_sys | Hold | 0.000 | 0
serial_clk | Setup | 0.000 | 0
serial_clk | Hold | 0.000 | 0
pixel_clk | Setup | 0.000 | 0
pixel_clk | Hold | 0.000 | 0

# Timing Details

## Path Slacks Table:

### Setup Paths Table

#### Report Command:report_timing -setup -max_paths 25 -max_common_paths 1
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
