hokuu1102/Gowin2026-PolySynth/sim/evidence/rightboard-vibrato-fix-20261008/timing-rightadc-fixed.html

# Timing Messages

Report Title | Timing Analysis Report
Design File | C:\Users\hokuu\Desktop\FPGA\FPGA2026\build\rightadc-probe\impl\gwsynthesis\Gowin2026.vg
Physical Constraints File | C:\Users\hokuu\Desktop\FPGA\FPGA2026\build\rightadc-probe\constr\top.cst
Timing Constraint File | C:\Users\hokuu\Desktop\FPGA\FPGA2026\build\rightadc-probe\constr\top.sdc
Tool Version | V1.9.12.03 (64-bit)
Part Number | GW5AT-LV60PG484AC1/I0
Device | GW5AT-60
Device Version | B
Created Time | Thu Oct 8 23:07:18 2026
Legal Announcement | Copyright (C)2014-2026 Gowin Semiconductor Corporation. All rights reserved.

# Timing Summaries

## STA Tool Run Summary:

Setup Delay Model | Slow 0.93V 0C C1/I0
Hold Delay Model | Fast 0.975V 85C C1/I0
Numbers of Paths Analyzed | 51175
Numbers of Endpoints Analyzed | 53287
Numbers of Falling Endpoints | 26
Numbers of Setup Violated Endpoints | 0
Numbers of Hold Violated Endpoints | 0
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
