hokuu1102/Gowin2026-PolySynth/files/10-硬件/原理图/righthand_board_A.pdf

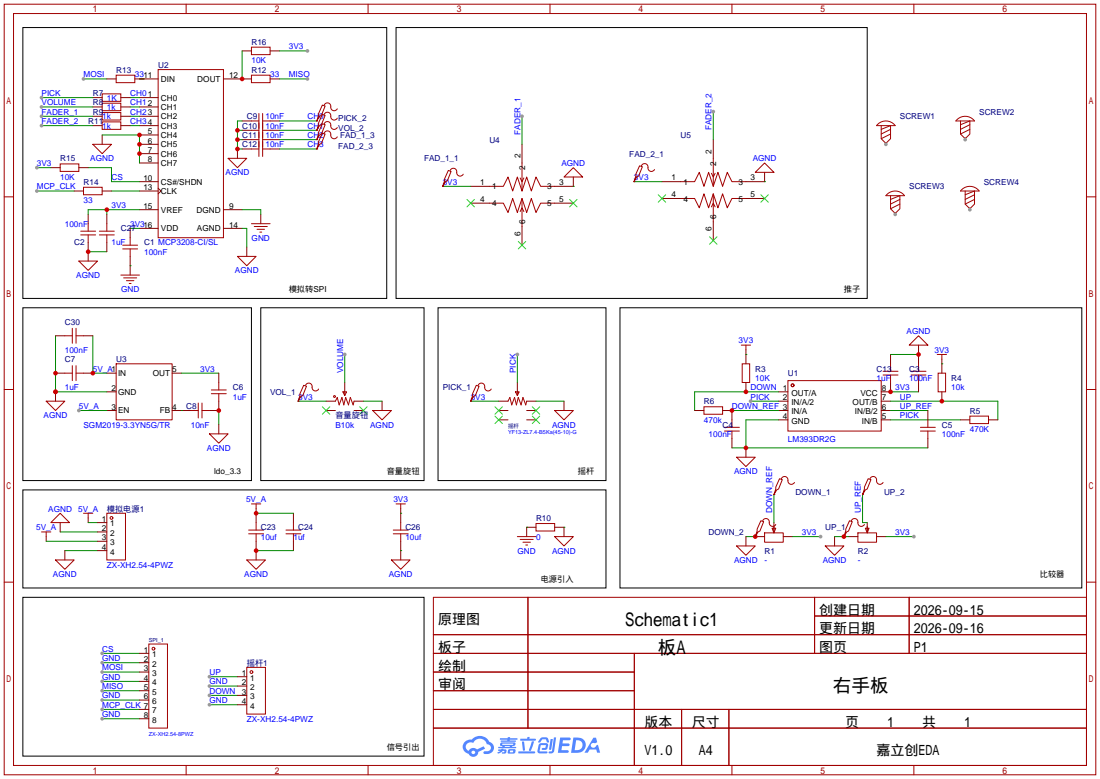
[picture p22: page 1]

原理图 | Schematic1 | 创建日期 | 2026-09-15

更新日期 | 2026-09-16

板子 | 板A | 图页 | P1
绘制 | | 右手板
审阅

V1.0 | A4 | 嘉立创EDA
