hokuu1102/Gowin2026-PolySynth/esp32/ble/main/ble_main.c

/*
 * ble_main.c -- ESP32-S3 BLE <-> UART 透传桥（⭐ S3 / BLE 版）
 * ============================================================================
 * 项目：FPGA2026 · ESP32 通路
 * 文档：files/20-代码/ESP32通路总体架构-20260922.md
 *       files/20-代码/FPGA侧对接清单-ESP32通路-20260922.md
 *
 * 【为什么有这一版】
 *   ⚠️ 初代 ESP32（有经典蓝牙 SPP）带 PSRAM 的开发板买不到，
 *   而手上那块 **ESP32-S3 有 PSRAM** ⇒ 用 S3 走 BLE 换大水池。
 *   🔴 代价：**BLE 在 PC 上不是 COM 口** ⇒ `evt2uart.py` 不能直接用。
 *
 * 【和 SPP 版的共同点（⭐ 这些是通路的核心，⛔ 两边必须一致）】
 *   ① 帧 = 9 字节（0xA5 + 8 字节大端事件）
 *   ② 🔴 **写 UART 恒为 9N 字节**（余数留到下次）—— 防帧被切分
 *   ③ 🔴 **一帧 9 字节一次写入 UART**
 *   ④ 复位序列 = 9 的整数倍（36 字节）
 *   ⑤ ⛔ 不解析事件内容（模式 A）
 *
 * 【⭐ 那条 9N 纪律为什么关键（两边一样）】
 *   FPGA 侧 rtl/w3c/evt_uart_rx.v:203 的空闲归位【只在帧中途】触发：
 *       idle_expired && (idx_q != 4'd0)
 *   ⇒ 帧间可任意停顿；🔴 只有一帧【内部】被打断才截帧。
 *   ⚠️ 门限随波特率【同比】变化（`GAP_BYTES = 16`，`evt_uart_rx.v:86`）：
 *      · **500 kbps（⭐ 当前档）** ⇒ 1 字节 = 20 µs ⇒ 门限 = **320 µs**
 *      · （⭐ 对照 1 Mbps：160 µs —— ⚠️ 已不用该档）
 *   ⚠️ 而 BLE 的数据是**按 ATT 包投递**的：一个 9 字节帧可能被切成两个包
 *      ⇒ 中间隔一个连接间隔（7.5~30 ms）⇒ 🔴 远超门限 ⇒ 必然截帧。
 *   ⇒ ⭐ 9N 对齐把"写进 UART 的永远凑成完整帧"这件事保证住。
 * ============================================================================
 */

#include <string.h>
#include <stdio.h>
#include <stdint.h>
#include <stdbool.h>

#include "freertos/FreeRTOS.h"
#include "freertos/task.h"

#include "esp_log.h"
#include "esp_err.h"
#include "esp_check.h"
#include "nvs_flash.h"

#include "esp_bt.h"
#include "esp_bt_main.h"
#include "esp_bt_device.h"
#include "esp_gap_ble_api.h"
#include "esp_gatts_api.h"
#include "esp_gatt_common_api.h"

#include "driver/uart.h"
#include "driver/gpio.h"

#include "esp_timer.h"
#include "esp_random.h"   /* 2026-10-14：每次上电换 BLE 随机地址 */

#include "ble_config.h"
#include "gatt_svc.h"
#include "pool.h"
#include "hmi.h"
#include "up_ring.h"
#include "ws2812.h"

static const char *TAG = "blebridge";

/* ===========================================================================
 * 可观测计数（K-106：容量有限/会出错的东西必须看得见）
 * =========================================================================== */
static volatile uint32_t s_ble_rx_bytes   = 0;
/* ⭐⭐ 2026-10-01（实测修 bug）：**本曲**已收事件数 —— ⭐ 屏上 `t2` / 进度条用
 * ---------------------------------------------------------------------------
 * 🔴 **为什么不能直接用 `s_ble_rx_bytes / FRAME_BYTES`**：
 *    ⚠️ 那个是**自开机累计**（⛔ 从不复位），⭐ 而总数 `s_song_total` 是**本曲**的
 *    ⇒ 🔴 **分子累计、分母本曲** ⇒ 灌两次 200 帧就显示 `410/200`、百分比 `205%`
 *    （⭐ 实测：用户接上屏后第一次看到的就是这个）。
 * ⭐ 本计数在【复位标记】处清零（⭐ 那就是"新曲子开始"的信号）。
 */
static volatile uint32_t s_song_events_rx = 0;
static volatile uint32_t s_ble_rx_dropped = 0;
static volatile uint32_t s_uart_tx_bytes  = 0;
static volatile uint32_t s_uart_rx_bytes  = 0;
/* ⭐ 2026-09-30：识别到的起播触发字符数（'S'/'X'/'R'）。
 * 🔴 用途：把"发了 S 没反应"一刀切成三段（⭐ 见 status 打印处的注释）：
 *    · `u_rx` 不动 ⇒ 物理层；`u_rx` 动而 `trig=0` ⇒ 字符没认出；`trig>0` ⇒ 看起播逻辑。 */
static volatile uint32_t s_trig_cnt       = 0;
static volatile uint32_t s_ble_tx_bytes   = 0;
static volatile uint32_t s_ble_tx_failed  = 0;
/* ⭐⭐ 2026-09-30（B 子集）：CMD 口（`0xABF3`）的命令计数
 * ⚠️ 分开记"认得"与"不认得" —— ⭐ 这样"发了没反应"能一刀切开：
 *    · `cmd_ok` 涨 ⇒ ⭐ 命令认得，去看它干了什么
 *    · `cmd_unk` 涨 ⇒ 🔴 **命令格式对不上**（⭐ 不是"没生效"） */
static volatile uint32_t s_cmd_ok        = 0;
static volatile uint32_t s_cmd_unknown   = 0;

/* ---- ⭐ 帧头分类相关（⭐ 详见下面 frame_filter 的说明）--------------------
 * ⚠️ 必须定义在这里：⭐ gatts 回调（数据入口）就要读 s_song_total，
 *    而它出现在文件前部 ⇒ 若把定义放在 frame_filter 附近会【undeclared】。
 */
static volatile uint32_t s_total_frames_rx = 0;   /* ⭐ 收到的总数帧数 */
static volatile uint32_t s_reset_frames_rx = 0;   /* 复位标记帧数 */
static volatile uint32_t s_unknown_frames  = 0;   /* 🔴 未知帧头帧数 */
static volatile uint32_t s_song_total      = 0;   /* ⭐ 曲谱总事件数（0=未知） */

/* ===========================================================================
 * 9N 对齐缓冲（⭐ 核心）
 * ===========================================================================
 * 生产者：GATT 写回调（BLE 包到达）
 * 消费者：排空任务 -> UART（模式 A）或 -> 水池（模式 B）
 *
 * ⚠️ 容量取 9 的整数倍（1026 = 9×114），使块边界天然落在帧边界上。
 */
#define ALIGN_BUF_CAP  (FRAME_BYTES * 114)   /* 1026 B */

static uint8_t s_buf[ALIGN_BUF_CAP];
static size_t  s_head = 0, s_tail = 0, s_cnt = 0;
static portMUX_TYPE s_buf_mux = portMUX_INITIALIZER_UNLOCKED;

/* GATT 状态 */
static esp_gatt_if_t s_gatts_if  = ESP_GATT_IF_NONE;
static uint16_t s_conn_id        = 0;
/* ⭐⭐ 2026-10-15：连接参数（供 STAT 暴露 + 排查"灌谱只有 1~4 KB/s"）。
 * 🔴 为什么要暴露：BLE 吞吐 ≈ 每间隔包数 × 载荷 ÷ 间隔，
 *   间隔 30ms => 96 KB/s，间隔 500ms => 5.8 KB/s —— 实测正好落在后者。
 * ⚠️ 本工程此前【从不】记录连接参数 ⇒ 无从判断，只能猜。现在有数据了。 */
static volatile uint32_t s_conn_int_ms  = 0;   /* 连接间隔（毫秒）*/
static volatile uint16_t s_conn_latency = 0;   /* 从机延迟 */
static volatile uint16_t s_conn_timeout = 0;   /* 监督超时（10ms 单位）*/
static uint16_t s_mtu            = 23;    /* ⚠️ 默认；协商后更新 */
static volatile bool s_connected = false;
static bool s_adv_configured     = false;

/* 属性句柄（⭐ 由属性表创建回调填） */
static uint16_t s_handle_recv = 0;   /* 对端写这里 */
static uint16_t s_handle_noti = 0;   /* 我们 notify 这里 */
static uint16_t s_handle_cmd  = 0;
static uint16_t s_handle_stat = 0;
/* ⭐⭐ 2026-09-30：0xABF2 的 CCCD 句柄 + "对端是否已使能通知" 标志
 * 🔴 为什么需要：⭐ 客户端**必须写 CCCD=0x0001** 才收得到 notify。
 *    ⚠️ 原来固件只看 `s_connected` ⇒ 🔴 **连接一建立就放水**，
 *      而那一刻客户端**还没订阅** ⇒ ⭐ 数据**全丢**（⚠️ 且 `fail=0`，看不出来）。
 *    ⭐ 实测铁证（2026-09-30）：连上后 700 ms 内 `u_out` 从 4000→4500
 *      （环排空了），⚠️ 而 PC 侧 **0 个包**。 */
static uint16_t s_handle_noti_cccd = 0;
static volatile bool s_noti_enabled = false;   /* ⭐ 对端已订阅 0xABF2 */

/* ⭐⭐ 2026-10-15：0xABF4(STAT) 的 CCCD 句柄 + "对端是否已订阅 STAT" 标志
 * ---------------------------------------------------------------------------
 * 🔴 为什么需要（出处：ESP32侧需求-STAT周期性notify-20261014.md）：
 *    STAT 原来只能靠客户端 `readValue()` 取 ⇒ ⚠️ 而 ESP32 在灌谱/播放期间
 *    忙于往 FPGA 转发，读回调得不到及时服务 ⇒ 🔴 读挂住 ⇒ 而 Web Bluetooth
 *    **无法取消**已发出的操作 ⇒ ⚠️ 浏览器之后每个操作都报
 *    `GATT operation already in progress` ⇒ **起播/停止/清池全失效**。
 * ✅ 改成周期性 notify 之后，客户端**订阅即可、不再读** ⇒ 从根上消除。
 * ⚠️ 与 `s_noti_enabled`（0xABF2）**分开**：两者是不同的 CCCD，
 *    客户端可能只订阅其中一个（⭐ 必须各自跟踪，⛔ 不能共用一个标志）。 */
static uint16_t s_handle_stat_cccd = 0;
static volatile bool s_stat_enabled = false;   /* ⭐ 对端已订阅 0xABF4 */

/* ⭐ 前向声明：`s_handle_recv`（CMD 0x01 分支）要用它，⛔ 而定义在其后 */
static void ble_buf_drop_tail(void);

/* ===========================================================================
 * 环形缓冲（只搬运，⛔ 不解析）
 * =========================================================================== */
/*
 * ⭐⭐ 2026-10-12 修根因（最终版）：帧相位 + 尾巴，两个都要顾。
 * ---------------------------------------------------------------------------
 * 🔴 原始写法：`while (wrote < n && s_cnt < CAP)` —— 空间剩 5 字节也写 5 字节
 *    ⇒ **一帧被切成两半** ⇒ 后续字节整体前移 ⇒ **帧相位永久错乱**
 *    ⇒ `frame_filter` 把字节当帧头 ⇒ 记成 `unk` 并丢弃。
 *    🔴 实测：5 轮循环压力后 `unk=50`（每轮凭空多 10 个"未知帧头"）。
 *
 * 🔴 中间版本：按整帧配额写，但把"不足一帧的尾巴"也算成 drop
 *    ⇒ ⚠️ 尾巴既没丢也没用，却被记账 ⇒ 守恒等式差 4~44 帧。
 *    🔴 指纹：**耗时异常（38.7 s）时必现** —— 那一刻 ATT 分包长度不整齐。
 *
 * ⭐ 最终做法（两件事一起做）：
 *    1. ⭐ 写入量 = 【能放下的整帧数 × 9】，保证**永远不截在帧中间**；
 *    2. ⭐ 没写进去的尾巴**留在静态残留里**，下次调用**拼在开头**
 *       ⇒ 尾巴既不丢、也不破坏相位。
 *    ⚠️ 残留最多 8 字节（一帧少 1），代价可忽略。
 */
static uint8_t s_tail_buf[FRAME_BYTES];   /* ⭐ 跨调用的残留（< 1 帧） */
static size_t  s_tail_len = 0;

/* ⭐ 丢掉不足一帧的残留（⭐ 清池时调用 —— 见 CMD 0x01 处说明） */
static void ble_buf_drop_tail(void)
{
    portENTER_CRITICAL(&s_buf_mux);
    s_tail_len = 0;
    portEXIT_CRITICAL(&s_buf_mux);
}

static size_t ble_buf_push(const uint8_t *src, size_t n)
{
    size_t wrote = 0;
    uint8_t merged[FRAME_BYTES * 2];

    /* ⭐ 先把"上次的残留 + 这次的开头"拼成一帧（如果凑得够） */
    if (s_tail_len > 0) {
        size_t need = FRAME_BYTES - s_tail_len;
        if (n >= need) {
            memcpy(merged, s_tail_buf, s_tail_len);
            memcpy(merged + s_tail_len, src, need);
            portENTER_CRITICAL(&s_buf_mux);
            {
                size_t room_frames = (ALIGN_BUF_CAP - s_cnt) / FRAME_BYTES;
                if (room_frames >= 1) {
                    for (size_t i = 0; i < FRAME_BYTES; i++) {
                        s_buf[s_head] = merged[i];
                        s_head = (s_head + 1) % ALIGN_BUF_CAP;
                        s_cnt++;
                    }
                    wrote = need;            /* ⭐ 本次消费掉的输入字节数 */
                    s_tail_len = 0;
                }
            }
            portEXIT_CRITICAL(&s_buf_mux);
            if (wrote == 0) {
                return 0;                    /* 环满，残留原样留着 */
            }
        } else {
            /* 还凑不满一帧 ⇒ 继续攒 */
            memcpy(s_tail_buf + s_tail_len, src, n);
            s_tail_len += n;
            return n;                        /* ⭐ 全部"收下"了（存在残留里） */
        }
    }

    /* ⭐ 剩下的部分按【整帧】写 */
    {
        size_t avail = n - wrote;
        portENTER_CRITICAL(&s_buf_mux);
        {
            size_t room_frames = (ALIGN_BUF_CAP - s_cnt) / FRAME_BYTES;
            size_t can = room_frames * FRAME_BYTES;
            size_t quota = (avail < can) ? avail : can;
            quota = (quota / FRAME_BYTES) * FRAME_BYTES;   /* ⭐ 只写整帧 */
            for (size_t i = 0; i < quota; i++) {
                s_buf[s_head] = src[wrote + i];
                s_head = (s_head + 1) % ALIGN_BUF_CAP;
                s_cnt++;
            }
            wrote += quota;
        }
        portEXIT_CRITICAL(&s_buf_mux);
    }

    /* ⭐ 剩下的尾巴存起来，下次拼 */
    if (wrote < n) {
        size_t left = n - wrote;
        if (left < FRAME_BYTES) {
            memcpy(s_tail_buf, src + wrote, left);
            s_tail_len = left;
            wrote = n;                       /* ⭐ 尾巴不算丢 —— 它被存下来了 */
        }
        /* left >= FRAME_BYTES ⇒ 真的是环满放不下，如实返回 wrote（算 drop） */
    }
    return wrote;
}

/*
 * ⭐ 取出【9 的整数倍】个字节 —— 本文件的灵魂。
 * 只有凑够一帧才吐，且吐出的块大小也是 9N。
 */
static size_t ble_buf_take_aligned(uint8_t *dst, size_t dst_cap)
{
    size_t take = 0;
    portENTER_CRITICAL(&s_buf_mux);
    {
        size_t aligned = (s_cnt / FRAME_BYTES) * FRAME_BYTES;
        if (aligned > dst_cap) {
            aligned = (dst_cap / FRAME_BYTES) * FRAME_BYTES;
        }
        for (take = 0; take < aligned; take++) {
            dst[take] = s_buf[s_tail];
            s_tail = (s_tail + 1) % ALIGN_BUF_CAP;
            s_cnt--;
        }
    }
    portEXIT_CRITICAL(&s_buf_mux);
    return take;
}

/* ===========================================================================
 * UART（给 FPGA）
 * =========================================================================== */
static esp_err_t uart_fpga_init(void)
{
    const uart_config_t cfg = {
        .baud_rate  = BLE_BAUD,
        .data_bits  = UART_DATA_8_BITS,
        .parity     = UART_PARITY_DISABLE,
        .stop_bits  = UART_STOP_BITS_1,
        .flow_ctrl  = UART_HW_FLOWCTRL_DISABLE,
        .source_clk = UART_SCLK_DEFAULT,
    };
    ESP_RETURN_ON_ERROR(
        uart_driver_install(BLE_UART_PORT, BLE_UART_RX_BUF, BLE_UART_TX_BUF, 0, NULL, 0),
        TAG, "uart_driver_install");
    ESP_RETURN_ON_ERROR(uart_param_config(BLE_UART_PORT, &cfg), TAG, "uart_param_config");
    ESP_RETURN_ON_ERROR(uart_set_pin(BLE_UART_PORT, BLE_PIN_UART_TX, BLE_PIN_UART_RX,
                                     UART_PIN_NO_CHANGE, UART_PIN_NO_CHANGE),
                        TAG, "uart_set_pin");
    /* 顺手把日志口钉到默认脚，避免 GPIO 上挂两份信号 */
    ESP_RETURN_ON_ERROR(uart_set_pin(BLE_LOG_UART_PORT, BLE_PIN_LOG_TX, BLE_PIN_LOG_RX,
                                     UART_PIN_NO_CHANGE, UART_PIN_NO_CHANGE),
                        TAG, "uart_set_pin(log)");

    ESP_LOGI(TAG, "UART%d ready: baud=%d tx=GPIO%d rx=GPIO%d",
             BLE_UART_PORT, BLE_BAUD, BLE_PIN_UART_TX, BLE_PIN_UART_RX);
    return ESP_OK;
}

/* ===========================================================================
 * BLE：广播
 * =========================================================================== */
static esp_ble_adv_params_t s_adv_params = {
    .adv_int_min        = 0x20,     /* 20 ms */
    .adv_int_max        = 0x40,     /* 40 ms */
    .adv_type           = ADV_TYPE_IND,
    /* 2026-10-13：由 PUBLIC 改为 RANDOM —— 绕开 Windows 的 MAC 级 GATT 缓存。
     *
     * ═══ 为什么必须换地址（而不是换名字）═══
     * 实测：Windows 按【MAC 地址】缓存 GATT 服务表，且【不理会】设备名。
     *   证据链：
     *     · 板子侧属性表创建 + StartService 全 OK（句柄 40~49）
     *     · 板子收到的 ATT 请求 = 【0 条】—— 客户端压根没问
     *     · 改设备名（Synth -> Synth2）后：能扫到了，但服务表还是 4 个
     *     · 发 Service Changed 指示：API 返回 ESP_OK，但服务表没变
     *     · 对照实验：同一台 PC 连【另一个】BLE 设备能正常发现其自定义服务
     *   => 缓存键是 MAC，所以只有【换 MAC】才能真正让它重新发现。
     *
     * ⚠️ 代价与注意：
     *   · 随机地址每次上电【可能不同】=> 每次都是"新设备"，⛔ 不会命中缓存
     *     （这正是我们要的；但也意味着【配对信息不持久】—— 本设备本来也不配对）
     *   · 地址类型必须与 set_rand_addr 配套，否则广播起不来
     *   · 静态随机地址的两个最高位必须是 11（BLE 规范），下面用固定值保证
     */
    .own_addr_type      = BLE_ADDR_TYPE_RANDOM,
    .channel_map        = ADV_CHNL_ALL,
    .adv_filter_policy  = ADV_FILTER_ALLOW_SCAN_ANY_CON_ANY,
};

/* BLE 随机静态地址（用户裁定：**每次上电自动换** —— 2026-10-14）。
 *
 * ═══ 为什么每次都要换 ═══
 * Windows 按【MAC 地址】缓存 GATT 服务表；缓存命中时它**不发起服务发现**，
 * 表现为"连上了但自己的特征一个都看不到"（BleakCharacteristicNotFoundError）。
 * 🔴 实测：**板子断电重启后**（地址不变）缓存会重新命中 => 又坏了。
 * => 只有"每次都换"才能稳定绕开。
 *
 * ⚠️ 代价（可接受）：
 *   · 每次上电 PC 都当成新设备 => 配对信息不持久
 *     （本设备本来也不配对，无影响）
 *   · 地址不可预期 => 靠【启动日志】保证可复现性：
 *     每次都会打印 `set_rand_addr XX:XX:... -> ESP_OK`
 *
 * ⚠️ 规范要求：**静态随机地址的最高两 bit 必须是 1**
 *    （第一个字节 bit7|bit6 = 0b11）=> 用 0xC0 掩码。
 *    ⛔ 不能全随机，否则被控制器拒绝或行为未定义。
 */
static esp_bd_addr_t s_rand_addr;

static void ble_gen_rand_addr(void)
{
    uint32_t r = esp_random();
    s_rand_addr[0] = (uint8_t)(0xC0 | (r & 0x3F));   /* 最高两位置 1（规范） */
    s_rand_addr[1] = (uint8_t)((r >> 6) & 0xFF);
    s_rand_addr[2] = (uint8_t)((r >> 14) & 0xFF);
    s_rand_addr[3] = (uint8_t)((r >> 22) & 0xFF);
    /* 后两字节用固定前缀，便于在扫描列表里一眼认出是本设备 */
    s_rand_addr[4] = 0x20;
    s_rand_addr[5] = 0x26;
}

static void ble_start_advertising(void)
{
    esp_ble_gap_start_advertising(&s_adv_params);
}

/* GAP 回调：⭐ 广播数据配好之后才真正开始广播 */
static void gap_event_handler(esp_gap_ble_cb_event_t event,
                              esp_ble_gap_cb_param_t *param)
{
    /* 🔴 2026-09-24 上机诊断：先确认【回调本身有没有被调用】。
     *    ⚠️ 现象：config_adv_data_raw 返回 OK，但
     *       ADV_DATA_SET_COMPLETE_EVT 永不触发 ⇒ 广播起不来。
     *    ⭐ 若这行也不出现 ⇒ GAP 回调压根没注册成功（问题在注册处）；
     *       若出现而 SET_COMPLETE 不来 ⇒ 事件真的没产生。 */
    ESP_LOGI(TAG, "GAP cb: event=%d", (int)event);

    switch (event) {
    /* 🔴🔴 2026-09-24 上机实测：这里曾是本工程最隐蔽的一个 bug ——
     *   配置广播用的是 esp_ble_gap_config_adv_data_raw()，
     *   它回调的是 ESP_GAP_BLE_ADV_DATA_RAW_SET_COMPLETE_EVT（枚举值 = 4），
     *   ⛔【不是】ESP_GAP_BLE_ADV_DATA_SET_COMPLETE_EVT（= 0）。
     *   ⚠️ 原来只 case 了 =0 的那个 ⇒ raw 事件落到 default 分支
     *      ⇒ ble_start_advertising() 永不调用 ⇒ 🔴 广播从未启动
     *      ⇒ 手机永远扫不到 "FPGA2026-Synth"。
     *   ⭐ 教训：换 API（adv_data -> adv_data_raw）时，
     *      必须【同时】改回调里的事件常量 —— 两者是配对的。
     *   ✅ 现在两个事件都处理，两种 API 谁都能用。 */
    case ESP_GAP_BLE_ADV_DATA_SET_COMPLETE_EVT:
    case ESP_GAP_BLE_ADV_DATA_RAW_SET_COMPLETE_EVT:
        s_adv_configured = true;
        ESP_LOGI(TAG, "adv data set (evt=%d) -> start advertising", (int)event);
        ble_start_advertising();
        break;

    case ESP_GAP_BLE_ADV_START_COMPLETE_EVT:
        /* ⚠️ adv_start_cmpl.status 的类型是 esp_bt_status_t，
         *    ⛔ 不能和 esp_gatt_status_t 的 ESP_GATT_OK 比
         *    （实测报 -Werror=enum-compare：两种枚举不同源）。
         *    ⭐ 该类型自己的成功值是 ESP_BT_STATUS_SUCCESS。 */
        if (param->adv_start_cmpl.status != ESP_BT_STATUS_SUCCESS) {
            ESP_LOGE(TAG, "adv start failed: 0x%X", param->adv_start_cmpl.status);
        } else {
            ESP_LOGI(TAG, "advertising as \"%s\"", BLE_DEV_NAME);
        }
        break;

    case ESP_GAP_BLE_UPDATE_CONN_PARAMS_EVT:
        /* ⭐⭐ 2026-10-15 新增：记录并打印【连接间隔】。
         *
         * 🔴 为什么要它（用户实测 + 算账）：
         *   灌谱实测只有 1~4 KB/s，而 BLE 正常能到 30~100 KB/s。
         *   ⭐ BLE 吞吐 ≈ 每间隔包数 × 载荷 ÷ 间隔：
         *     · 30 ms  => 6×480/0.03 = 96 KB/s
         *     · 500 ms => 6×480/0.5  = 5.8 KB/s   <= ⭐ 正好落在实测区间！
         *   ⇒ ⭐ 高度怀疑连接间隔被设得很长（本工程此前【从不】记录也【不】请求）。
         *   ⚠️ 间隔长还会导致"突发大 => 控制器 RX 缓冲溢出 => 丢包"，
         *     这与实测"丢了 35% 帧（ev=12261 / tf=18935）"吻合。
         * 📌 单位是 1.25 ms ⇒ ×1.25 才是毫秒（用 ×125/100 避免浮点）。 */
        s_conn_int_ms = (uint32_t)param->update_conn_params.conn_int * 125u / 100u;
        s_conn_latency = param->update_conn_params.latency;
        s_conn_timeout = param->update_conn_params.timeout;
        ESP_LOGW(TAG, "conn params: interval=%u (x1.25ms = %u ms) latency=%u timeout=%u status=0x%X",
                 (unsigned)param->update_conn_params.conn_int,
                 (unsigned)s_conn_int_ms,
                 (unsigned)param->update_conn_params.latency,
                 (unsigned)param->update_conn_params.timeout,
                 (unsigned)param->update_conn_params.status);
        break;

    default:
        break;
    }
}

/* ⭐⭐ 2026-09-30 夜：CMD 要用到起播/停止动作，而它们定义在【下方】（L732+）
 * ⇒ ⭐ 必须先【前置声明】，⛔ 否则编译报 implicit declaration。 */
static void start_action_play(void);
static void start_action_stop(void);
/* ⭐⭐ 2026-10-01 补：**原来这里漏了 `reset` 的前向声明** —— 🔴 那正是缺陷的源头
 * ---------------------------------------------------------------------------
 * 🔴 症状（实测）：⭐ 发 CMD `0x01`（复位）后，⭐ 屏上状态字**仍是 `断链`**，
 *    ⛔ 永远进不了 `待机`（⭐ `HMI_ST_IDLE` 成了死代码）。
 * ⭐ 根因链（⭐ 一路追到【第一因】）：
 *    ① ⚠️ 本处**只有 `play` / `stop` 的前向声明**，⛔ 没有 `reset`
 *    ② ⇒ ⭐ 于是 `case 0x01` 里**写不出** `start_action_reset()`（⭐ 未声明）
 *    ③ ⇒ ⚠️ 只能退而直接调 `pool_reset()`
 *    ④ ⇒ 🔴 **绕过了 wrapper** ⇒ `hmi_set_state(HMI_ST_IDLE)` 永不执行
 *    ⚠️ 而 662 行的注释写的恰恰是「**复用 `start_action_play/stop/reset`**」
 *       —— 🔴 **注释与代码相反**（⭐ 0.11 第 4 类检查要抓的正是这个）。
 * ⭐ 修法（改【上游源头】，⛔ 不是在下游打补丁）：
 *    ⭐ **补上缺失的声明** ⇒ 绕过的**理由**自然消失 ⇒
 *    ⭐ `case 0x01` 就能和 `0x03`/`0x04` 走同一条路。
 * 📌 教训：⭐ **"为什么这里没走公共封装"往往不是疏忽，而是【调不到】**
 *    ⇒ ⭐ 追根因时要问「⭐ **他为什么没这么写？**」（⭐ 而不是"他忘了"）。 */
static void start_action_reset(void);

#if WS2812_ENABLE || WS2812_CLEAR_ON_BOOT || BLE_LED_ENABLE
/* ===========================================================================
 * ⭐⭐ 2026-09-30 夜：连接指示灯（⭐ 用户 Q4 裁定）
 *        2026-10-01：⭐ 默认【关闭】+ ⭐ 开机【清锁存】（⭐ 用户："安全第一"）
 * ===========================================================================
 * ⭐ 用途：⭐ **不接串口屏也能一眼看出蓝牙连上没有**（⭐ 屏要 5V + 接线，灯不用）。
 *
 * ⭐ 两种灯的【统一入口】`ind_*` —— ⛔ 调用点不关心用的是哪种：
 *    · ⭐ `WS2812_ENABLE`  ⇒ **板载** WS2812（⭐ `GPIO48`，⚠️ 需短接 R17 跳线）
 *    · ⚠️ `BLE_LED_ENABLE` ⇒ **外接**普通 LED（⭐ 要接线）
 *   ⭐ **两者可同时开**（⚠️ 通常只用一个）。见 `ble_config.h` §12。
 *
 * 🔴🔴 **`WS2812_CLEAR_ON_BOOT` 必须也在守卫里**（⭐ 2026-10-01 修的）：
 *    ⚠️ 原来写的是 `#if WS2812_ENABLE` ⇒ 🔴 **关掉指示灯时，"清锁存"整段不编译**
 *    ⇒ ⚠️ 而 WS2812 是【锁存】的 ⇒ 🔴 **灯会永远停在旧颜色上，清不掉**。
 *    ⭐ 正确守卫：`WS2812_ENABLE || WS2812_CLEAR_ON_BOOT`。
 */
static void ind_init(void)
{
#if WS2812_ENABLE || WS2812_CLEAR_ON_BOOT
    /* ⭐ 无条件调 —— `ws2812_init()` 内部【自己会先发一帧全 0】（⭐ 清锁存），
     *    ⚠️ 这一步在 `WS2812_ENABLE=0` 时**恰恰是最需要的**。 */
    ws2812_init();
#endif
#if WS2812_ENABLE
    ws2812_set_connected(false);          /* ⚠️ 上电先灭（⭐ 指示灯开着时才需要） */
#endif
#if BLE_LED_ENABLE
    gpio_config_t io = {
        .pin_bit_mask = (1ULL << BLE_LED_GPIO),
        .mode         = GPIO_MODE_OUTPUT,
        .pull_up_en   = GPIO_PULLUP_DISABLE,
        .pull_down_en = GPIO_PULLDOWN_DISABLE,
        .intr_type    = GPIO_INTR_DISABLE,
    };
    if (gpio_config(&io) == ESP_OK) {
        gpio_set_level(BLE_LED_GPIO, BLE_LED_ACTIVE_HIGH ? 0 : 1);
        ESP_LOGI(TAG, "led: GPIO%d ready (%s active)",
                 BLE_LED_GPIO, BLE_LED_ACTIVE_HIGH ? "high" : "low");
    } else {
        ESP_LOGE(TAG, "led: gpio_config failed");
    }
#endif
}

static void ind_set(bool connected)
{
#if WS2812_ENABLE
    ws2812_set_connected(connected);
#endif
#if WS2812_ENABLE || WS2812_CLEAR_ON_BOOT || BLE_LED_ENABLE
    gpio_set_level(BLE_LED_GPIO,
                   connected ? (BLE_LED_ACTIVE_HIGH ? 1 : 0)
                             : (BLE_LED_ACTIVE_HIGH ? 0 : 1));
#endif
}
#endif /* WS2812_ENABLE || BLE_LED_ENABLE */

/* ===========================================================================
 * ⭐⭐ 2026-09-30（B 子集）：CMD 命令 —— 上报状态
 * ===========================================================================
 * ⭐ 语义：把当前状态**序列化成一行文本**，放进 `0xABF4`(STAT)。
 * 🔴 **STAT 是只读属性、⛔ 不能 notify** ⇒ 这只是"更新内容"，
 *    ⭐ **必须客户端主动读**才拿得到（⭐ 见 `gatt_svc.c` 的 `gatt_set_stat`）。
 *    ⇒ ⚠️ 所以这里**同时打日志** —— 否则分不清
 *      "命令没生效" 与 "生效了但客户端没读"。
 */
static void cmd_report_status(bool verbose)
{
    /* ⭐⭐ 2026-10-01（任务 2）：从"一行短文本"扩展成**八组完整状态**
     * -----------------------------------------------------------------------
     * 🔴 为什么扩：⚠️ 原来只有 `pool/sent/ovf/ring/u_drop` 几项
     *    ⇒ 🔴 **上位机看不到**：CMD 计数、环的 hwm/full、BLE 的 fail、
     *      MTU、订阅状态、帧统计、UART 触发计数… ⚠️ 只能盯串口日志。
     *
     * ⭐ 格式选择：⭐ **`key=value` 多行**（⭐ 既好读，⭐ 又好用正则解析）
     *    ⚠️ 不用二进制 —— 🔴 二进制在"人看一眼"时完全没用，
     *       而 ⭐ **排查现场最常见的就是"人看一眼"**。
     *
     * ⚠️ 容量：⭐ `s_val_stat` 是 **512 B**（⭐ 见 `gatt_svc.c`，2026-10-12 由 320 扩到 512）
     *    ⇒ ⭐ 下面这段最坏约 300 字符（⭐ 数值位数最大时）
     *    ⇒ ✅ 装得下（余量约 200 B）。
     * 🔴🔴 **加字段的【同一次提交】里必须重算长度并核对 `s_val_stat` 的容量** ——
     *    ⚠️ 截断是**静默的**，⛔ 不报错，只会"少一组"（⭐ 这个坑 2026-10-01
     *    和 2026-10-12 各踩一次，第二次是加 `ble.drop` + `frame.ev` 撑爆 320）。
     *    ⚠️ 而且长度**会随数值位数变化** ⇒ ⭐ 按【最坏情况】估，⛔ 不按典型值。
     * 🔴🔴 **但本地的 `buf` 必须【跟着一起扩】**（⭐ 2026-10-01 踩过）：
     *    ⚠️ 原来这里写的是 `char buf[256]`，⭐ 而 `s_val_stat` 已扩到 320
     *    ⇒ 🔴 **`snprintf` 在 256 处截断** ⇒ ⚠️ 最后一组 `cmd=` 只剩 `cmd=` + 垃圾
     *    （⭐ 实测原始字节：`...unk=0\ncmd=\x00\x00\x00\x00\x00\x1cG\x00\x00`）
     *    ⭐ **判据**：`stat_read.py` 的"八组齐全"检查**抓到了它**（⭐ 报"缺 cmd.ok/unk"）。
     *
     * 🔴🔴 **还有一个更危险的坑（⭐ 同一处，已修）**：
     *    ⚠️ **`snprintf` 的返回值是"【本该】写多少"**，⛔ **不是"实际写了多少"**
     *    ⇒ 原来写 `int n = snprintf(buf, sizeof(buf), ...); gatt_set_stat(buf, n);`
     *    ⇒ 🔴 截断时 `n = 264 > sizeof(buf) = 256`
     *    ⇒ 🔴 **从 256 字节的栈缓冲里读越界 8 字节**（⭐ 内存安全问题，⚠️ 而且不报错）
     *    ⇒ ⭐ **正解：用返回值之前先夹到 `sizeof(buf)`**（⭐ 见下面 `if (n > (int)sizeof(buf))`）。
     */
    char buf[512];
    pool_stats_t ps;
    up_ring_stats_t us;
    pool_stats(&ps);
    up_ring_stats(&us);

    /* ⭐⭐ 2026-10-01（C115 的第二层修法）：让【陈旧】变得可检测
     * -----------------------------------------------------------------------
     * 🔴 问题：⭐ `0xABF4` 是**请求时生成的快照** ⇒ ⚠️ 客户端**不请求就直读**
     *    会拿到**上一次**的内容，⚠️ 而**没有任何"这是旧的"标记**
     *    ⇒ 🔴 与真实状态**无法区分**（⭐ 实测：⭐ 池里明明有 200 帧，
     *       不请求直读却得到 `pool=0 sent=0` —— ⚠️ 而 0 看起来完全合理）。
     *
     * ⭐ 修法两层（⭐ 第一层在 PC 侧：读前先请求）：
     *    ① ⭐ `req=`  = **这是第几次快照**（⭐ 单调递增）
     *    ② ⭐ `up=`   = **生成快照时的开机毫秒数**
     *    ⇒ ⭐ 客户端**连读两次**：
     *        · `req` **没变** ⇒ 🔴 **数据是旧的**（⭐ 上次的）
     *        · `up` 与当前时间差太大 ⇒ 🔴 **快照很老**
     *    ⭐ 这就把"静默陈旧"变成了"**可判定的陈旧**" ✅
     * ⚠️ 同族经验：`C115`（⭐ 请求时才生成的快照接口）。 */
    static uint32_t s_stat_req = 0;
    s_stat_req++;
    int64_t up_ms = esp_timer_get_time() / 1000;

    /* ⭐ 屏→ESP32 诊断（⭐ 见 hmi.h） */
    uint32_t hmi_rx_b = 0, hmi_rx_t = 0;
    uint8_t  hmi_rx_last = 0;
    hmi_rx_stats(&hmi_rx_b, &hmi_rx_t, &hmi_rx_last);

    int n = snprintf(buf, sizeof(buf),
        "V1 mode=%s req=%lu up=%lldms\n"
        /* 池：已收/容量、已发、溢出、落后、应到/不符、限流截断、是否在跑
         * 2026-10-13 补 play/t0/lead/pv（播放位置）：
         *   消费方算法 heard_tick = play - t0 - lead；pv=1 表示值有效。
         *   为什么必须暴露：sent 只是"喂了多少"，起播后它会很快冲到满，
         *   而 FPGA 要再等 lead（约 10.4 秒）才出声
         *   => 拿 sent 当进度会让时间轴整体错位。 */
        "pool=%u/%u sent=%lu ovf=%lu late=%lu exp=%lu mm=%lu clamp=%lu run=%d "
        "play=%lu t0=%lu lead=%lu ttot=%lu pv=%d rate=%lu pum=%lu\n"
        /* ⭐ 上行环：⭐ 水位/容量、入/出、丢弃次数/字节、满次数、高水位、落哪 */
        "ring=%lu/%u in=%lu out=%lu drop=%lu/%lu full=%lu hwm=%lu %s\n"
        /* ⭐ BLE：⭐ 收/发字节、失败、MTU、连接、订阅
         * 🔴 2026-10-12 加 `drop`：BLE【收到】的字节并不全都进了水池 ——
         *    `ble_buf_push()` 满了会截断（返回 wrote < len），那些字节
         *    既不算进池、也不算进 `ovf` ⇒ ⚠️ 对账时凭空少一截。
         *    🔴 实测症状：发 18504 帧，`ble_rx/9` 与 `进池+ovf` 差 12~48 帧，
         *       而 `0xABF4` 里【没有任何字段】能解释这个差额
         *       ⇒ 违反"会出错的容量必须看得见"（K-106）。
         *    ⭐ 这里补上，让"收到的字节 = 进池 + 溢出 + 未知 + 复位 + 总数 + 丢"可闭环。 */
        "ble=rx%lu tx%lu fail=%lu drop=%lu mtu=%u conn=%d sub=%d\n"        /* ⭐ UART：⭐ 收字节、触发字符计数 */
        "uart=rx%lu trig=%lu\n"
        /* ⭐⭐ 2026-10-01：屏 → ESP32 方向（⭐ 诊断"屏有界面但数字不变"）
         *    ⭐ 判读：`hmi.rx` 涨 ⇒ 屏→ESP32 通 ⇒ 🔴 问题在反方向（ESP32→屏）
         * ⭐ 2026-10-12 补 `st=`（各状态的【进入次数】）：
         *    🔴 原因：`断链` 是转瞬即逝的过渡态 —— 断开时置 LINK_LOST，
         *       而重连成功后又立刻置回 READY，测试必须重连才能读 BLE
         *       => 永远读不到 `断链` => "断开到底有没有置断链"【不可观测】，
         *          正确实现和缺陷实现【读数一模一样】=> 判据无从下手。
         *    ⭐ 计数把它变成可事后读的数字（同族 C139：别让显示层掩盖内部真值）。
         *    ⭐ 判据：`st.lost` 必须 ≥ 1（断开过就必须涨过）。
         *    ⚠️ 只列 5 个关键的，避免这行过长（⭐ 320→512 扩容踩过截断的坑）。 */
        "hmi=rx%lu touch=%lu tx=%lu last=0x%02X "
        "st.i%lu l%lu r%lu p%lu x%lu\n"
        /* ⭐ 帧统计：⭐ 总数帧、曲谱总事件、复位帧、未知帧头
         * 🔴 2026-10-12 加 `ev=`（本曲已收事件数）：
         *    ⚠️ 用户报的 `18704/200` 修好之后，⭐ **从外部无法验证根因** ——
         *    因为 `hmi.c` 的显示兜底会把"已收 > 应到"钳到应到，
         *    于是屏上永远是 `200/200`，⛔ 看不出内部计数器有没有真的归零。
         *    ⭐ 判据必须能看见【真实内部值】⇒ 在这里暴露它（K-106：
         *    "会出错的状态必须看得见"）。
         *    ⭐ 判据：`ev` 应恒 ≤ `tf`；⭐ 若 `ev` 跨曲累加 ⇒ 就是那个缺陷复发。 */
        "frame=total=%lu tf=%lu ev=%lu rst=%lu unk=%lu\n"
        /* ⭐ CMD：⭐ 认得 / 不认得 */
        "cmd=ok%lu unk%lu\n",
        /* ---- 参数（⭐ 顺序必须与上面的格式串【严格一致】）---- */
#if BLE_MODE == BLE_MODE_B_POOL
        "B",
#else
        "A",
#endif
        /* ⭐ C115 第二层：⭐ 快照序号 + 生成时刻（⭐ 让陈旧可判定） */
        (unsigned long)s_stat_req, (long long)up_ms,
        (unsigned)ps.frames, (unsigned)ps.capacity_frames,
        (unsigned long)ps.sent_frames,
        (unsigned long)ps.overflow_frames,
        (unsigned long)ps.late_ticks_max,
        (unsigned long)ps.expected_frames,
        (unsigned long)ps.total_mismatch,
        (unsigned long)ps.tick_clamped_cnt,
        (int)ps.running,
        /* 播放位置（2026-10-13 新增）—— 顺序必须与格式串严格一致 */
        (unsigned long)ps.play_tick,
        (unsigned long)ps.t0_tick,
        (unsigned long)ps.lead_ticks,
        (unsigned long)ps.total_tick,
        (int)ps.pos_valid,
        (unsigned long)ps.rate_tick_per_s,
        (unsigned long)ps.pump_period_us,
        (unsigned long)us.level, (unsigned)us.cap,
        (unsigned long)us.in, (unsigned long)us.out,
        (unsigned long)us.drop_ev, (unsigned long)us.drop,
        (unsigned long)us.full_hits, (unsigned long)us.hwm,
        us.in_psram ? "PSRAM" : "DRAM",
        (unsigned long)s_ble_rx_bytes, (unsigned long)s_ble_tx_bytes,
        (unsigned long)s_ble_tx_failed, (unsigned long)s_ble_rx_dropped,
        (unsigned)s_mtu,
        (int)s_connected, (int)s_noti_enabled,
        (unsigned long)s_uart_rx_bytes, (unsigned long)s_trig_cnt,
        /* ⭐ 屏→ESP32 诊断（⭐ 见 hmi.h 的说明）
         * ⚠️ 末尾 5 个是【各状态的进入次数】：i=待机 l=灌谱中 r=就绪 p=播放中 x=断链
         *    🔴 为什么要它：`断链` 转瞬即逝（重连一成功就被置回就绪），
         *       测试必须重连才能读 BLE => 永远读不到它
         *       => "断开到底有没有置断链"【不可观测】，正确实现和缺陷实现读数一样。
         *    ⭐ 判据：`st.x`（断链进入次数）必须 ≥ 1。
         *    ⚠️ 主状态 `s_c.state` 本身也在 `0xABF4` 没暴露 —— 这里只给计数，
         *       因为计数才是【独立于读取时机】的判据。 */
        (unsigned long)hmi_rx_b, (unsigned long)hmi_rx_t, (unsigned long)hmi_tx_cmds(), (unsigned)hmi_rx_last,
        (unsigned long)hmi_state_enter_count(HMI_ST_IDLE),
        (unsigned long)hmi_state_enter_count(HMI_ST_LOADING),
        (unsigned long)hmi_state_enter_count(HMI_ST_READY),
        (unsigned long)hmi_state_enter_count(HMI_ST_PLAYING),
        (unsigned long)hmi_state_enter_count(HMI_ST_LINK_LOST),
        (unsigned long)s_total_frames_rx, (unsigned long)s_song_total,
        (unsigned long)s_song_events_rx,
        (unsigned long)s_reset_frames_rx, (unsigned long)s_unknown_frames,
        (unsigned long)s_cmd_ok, (unsigned long)s_cmd_unknown);

    if (n > 0) {
        /* 🔴🔴 必须夹住！⭐ `snprintf` 返回"本该写多少"，⚠️ 截断时会 > 缓冲大小
         *    ⇒ 不夹就**读越界**（⭐ 见上面注释里记的那个坑）。 */
        if (n > (int)sizeof(buf)) {
            ESP_LOGW(TAG, "STAT truncated: want %d, have %u", n, (unsigned)sizeof(buf));
            n = (int)sizeof(buf);
        }
        gatt_set_stat((const uint8_t *)buf, (size_t)n);
        /* ⚠️ 日志里**也打一份** —— ⭐ 否则分不清
         *    "命令没生效" 与 "生效了但客户端没读"（⭐ STAT 是只读的，⛔ 不会主动推）
         * ⭐⭐ 2026-10-15：⭐ **加 `verbose` 开关** —— 因为 `task_status` 现在
         *    每 `BLE_STAT_NOTIFY_PERIOD_MS`（300 ms）就要重拼一次 STAT 内容来发 notify
         *    ⇒ ⚠️ 每次都打这一大行会把串口日志刷爆（⭐ 而日志本身就是排查手段）
         *    ⇒ ⭐ **只有 CMD 0x02（人工请求）才打**，周期刷新走安静模式 ✅ */
        if (verbose) {
            ESP_LOGW(TAG, "STAT updated (%d B):\n%s", n, buf);
        }
    }
}

/* ⭐⭐ 2026-10-15：⭐ **把当前 STAT 内容用 notify 推给客户端**
 * ---------------------------------------------------------------------------
 * 🔴 为什么必须（出处：ESP32侧需求-STAT周期性notify-20261014.md）：
 *    见 `s_handle_stat_cccd` 的说明 —— 客户端 `readValue()` 会在 ESP32 忙于
 *    转发时挂住，而 Web Bluetooth 无法取消 ⇒ 🔴 浏览器永久卡死。
 *    ✅ 改成 notify 之后客户端**订阅即可、不再读** ⇒ 从根上消除。
 *
 * ⚠️ 发之前必须满足三个条件（⛔ 缺一个都别发）：
 *    ① `s_connected`   —— 没连接就没对象
 *    ② `s_handle_stat` —— 属性表还没建好时它是 0（⭐ 发了会失败）
 *    ③ `s_stat_enabled`—— ⭐ **客户端写了 STAT 的 CCCD=0x0001**
 *        （🔴 这是能否发 notify 的【真正前提】，⛔ 不是"已连接"——
 *          本项目为此栽过一次：连接一建立就放水 ⇒ 数据全丢，见 0xABF2 的注释）
 *
 * ⭐ 返回：是否真的发出去了（供调用方记账/诊断）✅ */
static bool stat_notify_now(void)
{
    if (!s_connected || s_handle_stat == 0 || !s_stat_enabled) {
        return false;
    }
    const uint8_t *st = NULL;
    size_t stn = gatt_get_stat(&st);
    if (st == NULL || stn == 0) {
        return false;
    }
    /* 🔴 第一个参数必须是【GATTS 接口】`s_gatts_if`，⛔ 不是 `ESP_GATT_IF_NONE`
     *    （= 0xFF）—— ⭐ 本项目踩过：那样会被当成 conn_id=255 ⇒
     *    蓝牙栈报 `Unknown connection ID: 255 fail sending notification`。
     *    📌 同一个坑在 `task_uart_to_ble` 里也踩过（⭐ 见那里的长注释）。 */
    esp_err_t err = esp_ble_gatts_send_indicate(
        s_gatts_if, s_conn_id, s_handle_stat, (uint16_t)stn, (uint8_t *)st, false);
    if (err != ESP_OK) {
        s_ble_tx_failed++;
        ESP_LOGW(TAG, "STAT notify failed: %s (if=%d conn=%d h=%u len=%u)",
                 esp_err_to_name(err), (int)s_gatts_if, (int)s_conn_id,
                 (unsigned)s_handle_stat, (unsigned)stn);
        return false;
    }
    s_ble_tx_bytes += stn;
    return true;
}

/* ===========================================================================
 * GATT 事件 —— ⭐ 全工程【唯一】的 gatts 回调
 * ===========================================================================
 * ⚠️ ESP-IDF 的 esp_ble_gatts_register_callback() 是【全局】的：
 *    注册两次会互相覆盖 ⇒ 症状是"回调只触发一半"，极难查。
 *    ⇒ ⭐ 属性表在 gatt_svc.c，事件处理全在这里。
 */
static void gatts_event_handler(esp_gatts_cb_event_t event,
                                esp_gatt_if_t gatts_if,
                                esp_ble_gatts_cb_param_t *param)
{
    switch (event) {
    case ESP_GATTS_REG_EVT:
        s_gatts_if = gatts_if;
        ESP_LOGI(TAG, "GATTS registered, app_id=%d if=%d", param->reg.app_id, gatts_if);
        esp_ble_gap_set_device_name(BLE_DEV_NAME);

        /* 2026-10-13：设置【随机静态地址】—— 与 s_adv_params.own_addr_type
         * = BLE_ADDR_TYPE_RANDOM 配套。
         * ⚠️ 顺序要求：必须在【开始广播之前】设好，否则广播用的是旧地址。
         * ⚠️ 必须在蓝牙协议栈使能之后调（本处在 REG_EVT 里，已使能）。
         * ⭐ 目的见 s_adv_params 上方的注释：绕开 Windows 按 MAC 缓存的 GATT 表。 */
        {
            /* 每次上电生成一个新地址（见 s_rand_addr 的注释） */
            ble_gen_rand_addr();
            esp_err_t ra = esp_ble_gap_set_rand_addr(s_rand_addr);
            ESP_LOGI(TAG, "set_rand_addr %02X:%02X:%02X:%02X:%02X:%02X -> %s",
                     s_rand_addr[0], s_rand_addr[1], s_rand_addr[2],
                     s_rand_addr[3], s_rand_addr[4], s_rand_addr[5],
                     esp_err_to_name(ra));
        }

        /* ⭐ 先把属性表建起来（句柄要从创建回调里拿） */
        esp_ble_gatts_create_attr_tab(gatt_get_db(), gatts_if,
                                      gatt_idx_count(), 0);

        /* 再配广播数据（⭐ GAP 回调里真正启动广播） */
        {
            /* ⭐⭐⭐ 2026-09-24 上机实测：改用【原始广播数据】API
             *
             * 经过（两级错误，逐个定位）：
             *   ① 原来 .service_uuid_len = 2 配 .p_service_uuid = &(uint16_t)
             *      ⇒ ⚠️ ESP-IDF 要求后者指向【16 字节完整 UUID】
             *      ⇒ 报 0x102 ESP_ERR_INVALID_ARG
             *      ⇒ ADV_DATA_SET_COMPLETE_EVT 永不触发 ⇒ 广播从未启动。
             *   ② 把 UUID 去掉（len=0）后，config 通过了，但启动广播报：
             *      🔴 BT_BTM: btm_ble_write_adv_enable_complete failed (0xD FAIL)
             *      ⚠️ 广播包只剩 Flags（结构体方式的隐式组装在
             *         include_name 未及时生效时可能产出无效包）。
             *
             * ⭐ 最终修法：用 esp_ble_gap_config_adv_data_raw() 【手工构造】
             *    标准 BLE 广播包 —— 每个字段的长度/类型都显式可控，
             *    ⛔ 不依赖结构体的隐式行为。
             *
             * ⭐ 包内容（标准 AD 结构，每条 = [长度][类型][数据]）：
             *    · Flags        : 02 01 06      (LE General Discoverable, BR/EDR Not Supported)
             *    · Complete Name: 0x0F 09 "FPGA2026-Synth"   (14 字符 + 类型 + 长度 = 16 B)
             *    ⚠️ 合计 3 + 16 = 19 B ≤ 31 B（BLE 4.x 广播包上限）✅
             */
            /* 广播数据 = Flags + 完整本地名。
             *
             * 🔴🔴 2026-10-13 修（两个缺陷叠在一起，都在这几行里）：
             *
             * 缺陷 A（原来就有）：名字和长度【都写死】，而且【互相不符】：
             *      static uint8_t adv_raw[] = {
             *          0x02, 0x01, 0x06,
             *          0x0F, 0x09,                    <- 声明 15 字节
             *          'F','P','G','A','2','0','2','6','-','S','y','n','t','h'
             *      };                                 <- 实际只有 14 个字符
             *   ⚠️ 后果：PC 按 15 字节取名字 => 越界 => 名字解析失败。
             *
             * 缺陷 B（我第一次修的时候引入的）：数组大小算式算错：
             *      2 + 2 + sizeof(BLE_DEV_NAME)-1            = 18   ✗
             *      正确 = Flags(3) + [len][type](2) + 名字(N) = N+5  ✓
             *   🔴 少 1 字节 => memcpy 把【名字的最后一个字符截掉】。
             *   实测证据（诊断日志打出的真实字节）：
             *      bytes = [02 01 06 0F 09 46 50 47 41 32 30 32 36 2D 53 79 6E 74]
             *               ^^^^^ 声明 15 字节，实际只跟了 13 个字符（缺 'h'）
             *   ⭐ 这解释了全部现象：板子日志说在广播、PC 却**收不到名字**
             *      （收到的是空包）=> "找不到设备"。
             *
             * 修法：由 BLE_DEV_NAME 自动生成，长度用【加法】而不是硬编码算式，
             *   并加编译期断言把总长钉死。⛔ 不再手写字符与长度。
             *   ⚠️ 改名时只需改 ble_config.h 一处。 */
            enum { ADV_NAME_LEN = sizeof(BLE_DEV_NAME) - 1 };   /* 设备名字节数 */
            /* 包结构（3 条 AD）：
             *   Flags              : 02 01 06
             *   完整 16 位 UUID 列表: 03 03 F0 AB      (0xABF0 小端)
             *   完整本地名          : (N+1) 09 <name>
             * ⭐ 2026-10-13 新增服务 UUID：
             *   🔴 为什么必须加：实测 PC 连上后只发现 4 个【GATT 强制服务】
             *      （2a05/2a00/2a01/2aa6），我们自己的 0xABF0 一个都没有。
             *      而广播包里【只有 Flags + 名字】—— 客户端从广播里
             *      拿不到"这个设备提供什么服务"的信息。
             *   ⭐ 标准做法是把服务 UUID 放进广播（AD type 0x03 = 完整列表），
             *      客户端据此建立服务表，⛔ 不必等连接后再逐个探。
             *   ⚠️ 代价：+4 字节（当前 3+4+2+15 = 24 ≤ 31 ✅）。 */
            static uint8_t adv_raw[3 + 4 + 2 + ADV_NAME_LEN];
            /* 编译期断言（三个都要）：
             *  · 包不能超过 31 字节 —— BLE 4.x 广播硬上限，超了广播会被拒，
             *    现象是"PC 扫不到"，极难定位；
             *  · 数组必须正好装下 —— 少了会静默截断名字（踩过）。 */
            _Static_assert(sizeof(adv_raw) <= 31,
                           "广播包超过 31 字节：BLE_DEV_NAME 太长了");
            _Static_assert(sizeof(adv_raw) == 9 + ADV_NAME_LEN,
                           "广播数组大小与内容不符（会截断名字）");
            adv_raw[0] = 0x02; adv_raw[1] = 0x01; adv_raw[2] = 0x06;   /* Flags */
            adv_raw[3] = 0x03; adv_raw[4] = 0x03;                      /* len=3, 完整 UUID16 列表 */
            adv_raw[5] = 0xF0; adv_raw[6] = 0xAB;                      /* 0xABF0 小端 */
            adv_raw[7] = (uint8_t)(ADV_NAME_LEN + 1);                  /* len = 名长+1 */
            adv_raw[8] = 0x09;                                        /* 完整本地名 */
            memcpy(&adv_raw[9], BLE_DEV_NAME, ADV_NAME_LEN);
            esp_err_t adv_err = esp_ble_gap_config_adv_data_raw(adv_raw,
                                                               sizeof(adv_raw));
            if (adv_err != ESP_OK) {
                ESP_LOGE(TAG, "config_adv_data_raw FAILED: 0x%X (%s)",
                         adv_err, esp_err_to_name(adv_err));
            } else {
                /* 2026-10-13 诊断：把【实际要广播的字节】打出来。
                 * 为什么需要：PC 侧实测收到的是【空广播包】（local_name=None、
                 *   无 manufacturer、无 service_uuid，只有 RSSI），
                 *   而固件每一步日志都说成功 —— 两边对不上。
                 *   ⭐ 只有把字节打出来才能确定是"我们发错了"还是"控制器没发"。 */
                char hexbuf[3 * sizeof(adv_raw) + 1];
                size_t hp = 0;
                for (size_t k = 0; k < sizeof(adv_raw) && hp + 3 < sizeof(hexbuf); k++) {
                    hp += snprintf(hexbuf + hp, sizeof(hexbuf) - hp, "%02X ", adv_raw[k]);
                }
                ESP_LOGI(TAG, "config_adv_data_raw OK (%u B), adv name = \"%s\", "
                         "bytes = [%s], waiting for SET_COMPLETE",
                         (unsigned)sizeof(adv_raw), BLE_DEV_NAME, hexbuf);
            }
        }
        break;

    case ESP_GATTS_CREAT_ATTR_TAB_EVT:
        if (param->add_attr_tab.status != ESP_GATT_OK) {
            ESP_LOGE(TAG, "create attr tab FAILED: 0x%X", param->add_attr_tab.status);
            break;
        }
        if (param->add_attr_tab.num_handle != gatt_idx_count()) {
            /* 🔴 句柄数不符 ⇒ 后面的索引全错位 ⇒ 必须当场报出来 */
            ESP_LOGE(TAG, "attr num mismatch: got %d want %d",
                     param->add_attr_tab.num_handle, gatt_idx_count());
            break;
        }
        s_handle_recv = param->add_attr_tab.handles[gatt_idx_recv()];
        s_handle_noti = param->add_attr_tab.handles[gatt_idx_noti()];
        s_handle_cmd  = param->add_attr_tab.handles[gatt_idx_cmd()];
        s_handle_stat = param->add_attr_tab.handles[gatt_idx_stat()];
        /* ⭐ 记下 CCCD 的句柄 —— ⭐ 下方 WRITE_EVT 靠它识别"对端订阅了" */
        s_handle_noti_cccd = param->add_attr_tab.handles[gatt_idx_noti_cccd()];
        /* ⭐⭐ 2026-10-15：STAT 的 CCCD 句柄（⭐ 见文件上方 `s_handle_stat_cccd` 的说明）
         * ⚠️ 必须在这里取 —— 属性表创建回调是**唯一**能拿到真实句柄的地方，
         *    而 WRITE_EVT 靠它识别"对端订阅了 STAT"（⛔ 不能靠"已连接"）。 */
        s_handle_stat_cccd = param->add_attr_tab.handles[gatt_idx_stat_cccd()];

        gatt_log_layout(param->add_attr_tab.handles[0], s_handle_recv,
                        s_handle_noti, s_handle_cmd, s_handle_stat);

        esp_ble_gatts_start_service(param->add_attr_tab.handles[0]);
        ESP_LOGI(TAG, "service started");
        break;

    case ESP_GATTS_CONNECT_EVT:
        s_conn_id   = param->connect.conn_id;
        s_connected = true;
        ESP_LOGI(TAG, "BLE CONNECTED conn_id=%d", s_conn_id);
        hmi_set_bt_connected(true);
        /* ⭐⭐ 2026-10-15 新增：主动请求【快速连接间隔】。
         *
         * 🔴 为什么要请求（用户实测 + 算账）：
         *   灌谱实测只有 1~4 KB/s，而 BLE 正常 30~100 KB/s。
         *   ⭐ 吞吐 ≈ 每间隔包数 × 载荷 ÷ 间隔：
         *     30 ms => 96 KB/s；500 ms => 5.8 KB/s（正好是实测区间）。
         *   ⚠️ 本工程此前【从不】请求连接参数 ⇒ 完全由中心设备（Windows/Chrome）决定，
         *     而它的默认值可能很保守。
         *   ⚠️ 间隔长还会"突发大 => 控制器 RX 缓冲溢出 => 丢包"，
         *     与实测"丢 35% 帧"吻合 ⇒ ⭐ 这一处可能同时解释【慢】和【丢】。
         *
         * 📌 参数取 15~30 ms：够快（理论 60~90 KB/s），又不过激
         *   （⛔ 不要取 7.5 ms：那会挤占其它连接、也更容易被中心设备拒绝）。
         * ⚠️ 中心设备有权【拒绝】—— 所以下面仍会打印实际生效值（见 GAP 的
         *   UPDATE_CONN_PARAMS 分支），⭐ 以实测值为准，⛔ 不以"我请求了"为准。 */
        {
            esp_ble_conn_update_params_t cp = {0};
            memcpy(cp.bda, param->connect.remote_bda, sizeof(esp_bd_addr_t));
            cp.min_int = 12;    /* 12 × 1.25 = 15 ms */
            cp.max_int = 24;    /* 24 × 1.25 = 30 ms */
            cp.latency = 0;
            cp.timeout = 400;   /* 400 × 10ms = 4 s */
            esp_err_t cerr = esp_ble_gap_update_conn_params(&cp);
            ESP_LOGW(TAG, "request fast conn params (15~30 ms): %s",
                     esp_err_to_name(cerr));
        }
        /* 🔴🔴 2026-10-13：连上就发【GATT 服务变更指示】（0x2A05）。
         *
         * ═══ 为什么必须发（这是"服务发现只有 4 个"的修法）═══
         * 实测症状：PC 连上后只发现 4 个 GATT 强制特征
         *   （2a05/2a00/2a01/2aa6），我们自己的 0xABF0 一个都没有。
         * 决定性证据：
         *   · 板子日志：属性表创建 + StartService 全部成功（句柄 40~49）
         *   · 板子收到的 ATT 请求：【0 条】—— 客户端压根没问
         *   · 对照实验：同一台 PC 连【另一个】BLE 设备，能正常发现它的
         *     自定义服务（fe55）=> ⛔ 不是 PC 无能
         *   => 结论：Windows 用了【按 MAC 缓存的旧服务表】，
         *      认定"这个设备只有 4 个服务"，于是【不发起服务发现】。
         *
         * ⭐ 修法：BLE 规范里有专门打破这件事的机制 ——
         *   "Service Changed" 指示（characteristic 0x2A05）。
         *   客户端收到它之后【必须】丢弃缓存并重新发现服务。
         *   ⚠️ 而 0x2A05 正好就在 PC 看到的那 4 个特征里
         *      => 说明 Windows 认这个机制，只是我们从来没发过。
         *
         * ⚠️ 时机：必须在【连接建立之后】发（连接前没有接收方）。
         * ⚠️ 副作用：客户端会重新做一次服务发现（多几百毫秒），
         *    ⛔ 无害 —— 这正是我们要的。
         * 📌 它同时解决了"刷固件后服务变了但客户端不知道"这个通用问题：
         *    以后改 GATT 结构，客户端也能自动跟上，⛔ 不用清缓存。 */
        if (s_gatts_if != ESP_GATT_IF_NONE) {
            esp_err_t sci = esp_ble_gatts_send_service_change_indication(
                                s_gatts_if, NULL);   /* NULL = 发给所有已连设备 */
            ESP_LOGI(TAG, "service change indication -> %s",
                     esp_err_to_name(sci));
        }

        /* 重连恢复：从断链回到"就绪"（用户 2026-10-12 裁定）
         * -----------------------------------------------------------------
         * 未修之前的行为：断开时置 LINK_LOST，重连后【无人复位】
         *   => 屏上一直挂着"断链"，直到有新数据到达才被动走掉。
         *   后果：断链期间板子其实已经恢复可用了，用户却以为还断着。
         *
         * 语义（用户裁定）：重连成功 => 屏上显示"就绪"。
         *   注意：这里用 READY 而不是 IDLE，因为 IDLE 的语义是
         *   "池是空的、什么都没装"；而重连时池里往往还留着上一曲的谱，
         *   把它说成"待机"会误导人去按起播。READY 的语义是"有谱、可以起播"。
         *
         * 只在【当前确实是 LINK_LOST】时才动状态，避免把
         * 播放中/灌谱中这类正常状态误拉回就绪。
         * 同族教训 C141：条件要写全，别只看"连上了"这一个信号。 */
        if (hmi_get_state() == HMI_ST_LINK_LOST) {
            hmi_set_state(HMI_ST_READY);
            ESP_LOGI(TAG, "BLE 重连：屏上状态 断链 -> 就绪");
        }
#if WS2812_ENABLE || WS2812_CLEAR_ON_BOOT || BLE_LED_ENABLE
        /* ⭐⭐ 2026-09-30 夜：连上就点亮（⭐ 用户 Q4「让灯亮一下」）
         * ⚠️ 注意：⭐ 这里只是"物理连接"，⚠️ **还未订阅**（CCCD）。
         *    🔴 所以【放水】绝不能在这里开始 —— ⭐ 那会发进虚空
         *    （⭐ 实测：连上后 700ms 内环被排空，PC 侧 0 个包）。
         *    ⭐ 灯的语义是"连上了"，⭐ 放水的语义是"订阅了"，
         *    ⚠️ **两者刻意分开**（⭐ 灯早就亮，不代表数据能发）。 */
        ind_set(true);
#endif

        /* ⭐ 立刻请求大 MTU（⚠️ 默认 23 ⇒ 有效载荷仅 20 字节，整曲要 5200+ 包） */
        esp_ble_gatt_set_local_mtu(BLE_PREFERRED_MTU);
        break;

    case ESP_GATTS_DISCONNECT_EVT:
        /* 2026-10-12 诊断：先无条件打一条 INFO，确认本回调【到底进没进】。
         *   🔴 实测背景：断开后日志里【完全没有】DISCONNECT 字样，
         *      而 `st.x`（断链进入次数）恒为 0 => 怀疑本回调根本没触发。
         *      ⚠️ 但原来的日志在 `conn_id` 判断【之后】，
         *        所以"回调进了但被 break 掉"和"回调没进"看起来一样。
         *      ⭐ 把日志提到最前面，两种可能立刻分开。 */
        ESP_LOGI(TAG, "DISCONNECT_EVT 进入：conn_id=%d（s_conn_id=%d）reason=0x%02X",
                 param->disconnect.conn_id, s_conn_id,
                 param->disconnect.reason);
        /* 2026-10-12 竞态修复：先认领事件，再做任何清理。
         *
         * 根因：本回调原来【无条件】执行清理并置 LINK_LOST，不校验 conn_id。
         *   Bluedroid 的回调是异步投递的，重连够快时
         *   旧连接的 DISCONNECT 可能【晚于】新连接的 CONNECT 落地：
         *     ① CONNECT(新)     -> 恢复逻辑置「就绪」、s_connected=true
         *     ② DISCONNECT(旧)  -> 无条件又打回「断链」，还把 s_connected
         *                          和 s_noti_enabled 一起清掉
         *     => 屏上停在「断链」，链路其实好好的；而且因为 CCCD 被清，
         *        数据也不再放水（放水要求 s_connected && s_noti_enabled）。
         *   这正是 _idle_probe.py 列的第 (c) 种可能
         *   「有东西把状态又打回 LINK_LOST」。
         *
         * 修法：用 conn_id 认领 —— 只有当断的【就是】当前记录的那条连接时才处理。
         *   ⚠️ 判断必须放在【所有清理之前】，否则过期事件照样会污染当前连接。 */
        if (param->disconnect.conn_id != s_conn_id) {
            ESP_LOGW(TAG, "忽略过期断连事件 conn_id=%d（当前=%d）",
                     param->disconnect.conn_id, s_conn_id);
            break;
        }
        s_connected = false;
#if WS2812_ENABLE || WS2812_CLEAR_ON_BOOT || BLE_LED_ENABLE
        ind_set(false);                   /* ⭐ 断开 ⇒ 灭 */
#endif
        /* ⭐⭐ 2026-09-30：订阅状态**随连接失效** ⇒ ⭐ 必须清掉
         *    ⚠️ 否则重连后、客户端**还没订阅**时，固件会以为"可以发了"
         *    ⇒ 🔴 又把数据发进虚空（⭐ 这正是本次要修的缺陷）。
         * ⭐ 清掉 ⇒ 回到**蓄水**态，⭐ 等新对端订阅后再放水。 */
        s_noti_enabled = false;
        /* ⭐⭐ 2026-10-15：STAT 的订阅标志**同样随连接失效** ⇒ 必须一起清
         *    ⚠️ 否则重连后、客户端还没订阅时，`task_status` 会往 STAT
         *    发 notify ⇒ 🔴 发进虚空（⭐ 与上面 0xABF2 那条同一个道理）。 */
        s_stat_enabled = false;
        ESP_LOGW(TAG, "BLE DISCONNECTED, reason=0x%02X", param->disconnect.reason);
        /* ⭐ 屏上：蓝牙断开 + 状态字切"断链"
         *    ⚠️ 这正是模式 B 的核心卖点，⭐ 必须让人【看得见】 */
        hmi_set_bt_connected(false);
        hmi_set_state(HMI_ST_LINK_LOST);
        ble_start_advertising();          /* 重连 */
        break;

    case ESP_GATTS_MTU_EVT:
        s_mtu = param->mtu.mtu;
        ESP_LOGI(TAG, "MTU negotiated = %d (payload %d)", s_mtu, s_mtu - 3);
        break;


    /*
     * ⭐ 收到对端写数据 —— 这是"数据入口"
     * ⚠️ 注意：这里【只入缓冲区】，真正的转发由排空任务做。
     *    ⛔ 不要在回调里做重活（官方 SPP 示例明确警告会阻塞蓝牙栈）。
     */
    case ESP_GATTS_WRITE_EVT: {
        uint16_t h = param->write.handle;
        uint16_t len = param->write.len;
        const uint8_t *val = param->write.value;

        /* 2026-10-13 诊断：把客户端【写的每个句柄】都打出来（同 READ 的理由）。
         * ⚠️ 这条会给每次灌谱写都打一行 —— 所以只在【非数据口】时打，
         *    避免淹没日志（数据口是 0xABF1，灌谱时每秒几十次）。 */
        if (h != s_handle_recv) {
            ESP_LOGI(TAG, "WRITE_EVT handle=%u len=%u conn=%u",
                     (unsigned)h, (unsigned)len, (unsigned)param->write.conn_id);
        }

        /* ⭐⭐ 2026-09-30：**先识别 CCCD 写入** —— 这是"对端已就绪"的唯一可靠信号
         * -----------------------------------------------------------------
         * 🔴 为什么必须在这里判：⭐ 0xABF2 的 CCCD 写 `0x0001` 才代表
         *    客户端**真的开了通知**。⚠️ 在此之前任何 notify 都是**发进虚空**
         *    （⭐ 实测：连上后 700 ms 内环被排空，⚠️ 而 PC 收到 **0 个包**，
         *      且 `fail=0` ⇒ 🔴 完全看不出来）。
         * ⭐ 语义：⭐ **蓄水 → （对端订阅）→ 放水** ——
         *    ⚠️ 触发点是【订阅】，⛔ 不是【连接】。 */
        if (h == s_handle_noti_cccd && len >= 2) {
            uint16_t cccd = (uint16_t)(val[0] | (val[1] << 8));
            s_noti_enabled = (cccd & 0x0001) != 0;
            ESP_LOGW(TAG, "CCCD 0xABF2 = 0x%04X -> notifications %s",
                     (unsigned)cccd, s_noti_enabled ? "ENABLED" : "disabled");
            /* ⚠️ CCCD 写也要回响应（⭐ 它是 Write Request） */
            if (param->write.need_rsp) {
                esp_ble_gatts_send_response(gatts_if, param->write.conn_id,
                                            param->write.trans_id, ESP_GATT_OK, NULL);
            }
            break;
        }

        /* ⭐⭐ 2026-10-15：**STAT(0xABF4) 的 CCCD** —— 客户端订阅 STAT 通知
         * -----------------------------------------------------------------------
         * 🔴 为什么要单独跟踪：⭐ 它与 0xABF2 是**两个不同的 CCCD**，
         *    客户端可能只订阅其中一个 ⇒ ⛔ 不能共用 `s_noti_enabled`。
         * ⚠️ 只有这里置位之后，`task_status` 才会往 STAT 发 notify
         *    （⭐ 对没订阅的连接发是没意义的，而且会白占带宽）。 */
        if (h == s_handle_stat_cccd && len >= 2) {
            uint16_t cccd = (uint16_t)(val[0] | (val[1] << 8));
            s_stat_enabled = (cccd & 0x0001) != 0;
            ESP_LOGW(TAG, "CCCD 0xABF4(STAT) = 0x%04X -> periodic notify %s (period %d ms)",
                     (unsigned)cccd, s_stat_enabled ? "ENABLED" : "disabled",
                     BLE_STAT_NOTIFY_PERIOD_MS);
            if (param->write.need_rsp) {
                esp_ble_gatts_send_response(gatts_if, param->write.conn_id,
                                            param->write.trans_id, ESP_GATT_OK, NULL);
            }
            break;
        }

        /* ⭐⭐ 2026-09-30（B 子集）：**`0xABF3`(CMD) 单独解析** —— ⛔ 不再当曲谱数据
         * -----------------------------------------------------------------
         * 🔴 **原来这里是个真缺陷**：判据写成
         *      `if (h == s_handle_recv || h == s_handle_cmd)`
         *    ⇒ ⚠️ 往 CMD 口写的东西**被当成曲谱数据塞进缓冲**
         *    ⇒ 🔴 **CMD 口等于废的**（⭐ 写了什么后果都不可控）。
         *
         * ⭐ 本步只实现【与架构无关】的两个命令（⭐ 见下）：
         *      `0x01` = 清池（`pool_reset`）      —— ✅ 无争议
         *      `0x02` = 上报状态（写 `0xABF4`）   —— ✅ 无争议
         * ⛔ **刻意不做**：起播 / 停止 / 清环
         *    ⇒ ⚠️ 因为"起播归谁管"**尚未裁定**（方案③ vs 模式B 互斥）
         *    ⇒ ⭐ 见 `files/20-代码/矛盾裁定单-方案3与模式B-20260930.md`
         *    ⛔ **不要顺手加** —— 那会与未定的架构冲突。 */
        if (h == s_handle_cmd) {
            for (uint16_t i = 0; i < len; i++) {
                uint8_t c = val[i];
                switch (c) {
                case 0x01:                       /* ⭐ 清池 */
                    ESP_LOGW(TAG, "CMD 0x01: pool reset");
                    /* ⭐⭐ 2026-10-01 修：⭐ 改走 `start_action_reset()`（⭐ 与 0x03/0x04 一致）
                     * -----------------------------------------------------------------
                     * 🔴 原来这里直接调 `pool_reset()` ⇒ ⚠️ **绕过了 wrapper**
                     *    ⇒ 🔴 `hmi_set_state(HMI_ST_IDLE)` 永不执行
                     *    ⇒ ⭐ 屏上状态字**永远进不了 `待机`**（⭐ 实测坐实）。
                     * ⚠️ 为什么原来会绕过：⭐ 见上方 `start_action_reset` 的前向声明处
                     *    —— 🔴 **它当时根本没被声明，所以调不到**。
                     * ⭐ wrapper 里做的是「`pool_reset()` ＋ 推屏状态」——
                     *    ⭐ 两件事必须**一起**发生，⛔ 不能只做一半。 */
                    start_action_reset();
                    /* ⭐ 2026-10-12：清池时【同时丢掉不足一帧的残留】——
                     * ⚠️ 否则上一曲的半帧会和下一曲的开头拼成一个假帧
                     *    （⭐ 帧相位正确、内容却是两曲拼的 ⇒ 极难查）。 */
                    ble_buf_drop_tail();
                    s_cmd_ok++;
                    break;
                case 0x02:                       /* ⭐ 上报状态（写 0xABF4） */
                    ESP_LOGW(TAG, "CMD 0x02: status report requested");
                    cmd_report_status(true);   /* ⭐ verbose：人工请求 ⇒ 打日志 */
                    s_cmd_ok++;
                    break;
                /* ⭐⭐ 2026-09-30 夜新增（⭐ 用户 Q1 裁定后【不再被阻塞】）
                 * -----------------------------------------------------------------
                 * 🔴 **为什么原来不做**：⚠️ "起播归谁管"当时**未裁定**
                 *    （方案③ vs 模式B 互斥）⇒ ⭐ 怕与未定的架构冲突。
                 * ✅ **现已拍板**：⭐ **走模式 B，起播键在 ESP32**
                 *    ⇒ 📌 出处 `files/20-代码/用户裁定结果-20260930.md` §〇
                 *
                 * ⭐ 语义：
                 *    `0x03` ⇒ ⭐ **起播**（= 串口 `S` 的等价物）
                 *    `0x04` ⇒ ⭐ **停止**（= 串口 `X`）
                 * ⚠️ 复用 `start_action_play/stop/reset` ——
                 *    ⭐ 它们**已带判据**（池空则拒绝、已在跑则忽略），
                 *    ⛔ 不另写一套，避免两条路径行为不一致。 */
                case 0x03:                       /* ⭐ 起播 */
                    ESP_LOGW(TAG, "CMD 0x03: START (play)");
                    start_action_play();
                    s_cmd_ok++;
                    break;
                case 0x04:                       /* ⭐ 停止 */
                    ESP_LOGW(TAG, "CMD 0x04: STOP");
                    start_action_stop();
                    s_cmd_ok++;
                    break;
                /* ⭐⭐ 2026-10-01：CMD `0x20` = **探针**（⭐ 排查"屏上某栏不更新"）
                 * -----------------------------------------------------------------
                 * 🔴 症状（实测）：⭐ `t2`/`j0`/`n0` 都生效，⚠️ 但 `t3` 不生效
                 *    ⇒ ⚠️ 无法区分：① 屏上【没有】这个控件（⭐ 名字不对）
                 *                  ② 有控件但属性名/命令写错
                 * ⭐ 修法：⭐ **用 TJC 的 `get` 让屏【自己回答】** ——
                 *    · ⭐ 控件存在 ⇒ 屏回它的值（⭐ 会出现在 `hmi_poll_rx` 的日志里）
                 *    · 🔴 控件不存在 ⇒ **屏【不回复】**（⭐ 静默）
                 *    ⇒ ⭐ **"回没回"就是判据**，⛔ 不用猜。
                 * ⚠️ 同时问 `t2`（⭐ 已知能用的）当**对照组** ——
                 *    ⭐ 它一定回，⭐ 这样能证明"`get` 这条路本身是通的"。 */
                case 0x20:                       /* ⭐ 探针：问屏要几个控件的值 */
                    ESP_LOGW(TAG, "CMD 0x20: HMI probe (get)");
                    hmi_send_cmd("get t2.txt");  /* ⭐ 对照组：已知能用 */
                    hmi_send_cmd("get t3.txt");  /* 🔴 嫌疑：不生效 */
                    hmi_send_cmd("get t1.txt");  /* ⭐ 状态字 */
                    hmi_send_cmd("get g0.txt");  /* ⭐ 曲谱名 */
                    s_cmd_ok++;
                    break;
                /* ⭐⭐ CMD `0x21` = **直接给屏发一条原样命令**（⭐ 台面调测用）
                 *    ⚠️ 格式：`0x21` + ASCII 命令正文（⛔ 不用带 `FF FF FF`，固件补）
                 *    ⭐ 用途：⭐ 试"控件名/属性名/颜色值"到底哪个才对 ——
                 *       ⛔ 否则每试一次都要重新烧固件。 */
                case 0x21: {
                    char raw[BLE_HMI_CMD_MAX];
                    size_t rn = (len > (uint16_t)(i + 1)) ? (size_t)(len - i - 1) : 0;
                    if (rn >= sizeof(raw)) {
                        rn = sizeof(raw) - 1;
                    }
                    if (rn > 0) {
                        memcpy(raw, val + i + 1, rn);
                        raw[rn] = '\0';
                        ESP_LOGW(TAG, "CMD 0x21: raw HMI -> \"%s\"", raw);
                        hmi_send_cmd(raw);
                        s_cmd_ok++;
                    } else {
                        ESP_LOGW(TAG, "CMD 0x21: empty payload, ignored");
                    }
                    i = len;                     /* ⚠️ 正文已消费完 ⇒ 结束本批 */
                    break;
                }
                /* ⭐⭐ CMD `0x22` = **设置曲谱名**（⭐ 2026-10-01 新增，⭐ 用户裁定）
                 * -----------------------------------------------------------------
                 * 🔴 为什么需要它：⭐ 实测发现 `hmi_set_song()` **全工程零调用**
                 *    ⇒ ⭐ `s_c.song` 永远是初值 `----` ⇒ 🔴 **屏上曲名永远是 `----`**
                 *    ⚠️ 而 9 字节事件帧里**没有曲名字段**（⭐ `tick/inc/axis/vel/
                 *       kind/timbre` 已占满）⇒ ⭐ 曲名**只能由 PC 另外下发**。
                 * ⭐ 格式：`0x22` + UTF-8 曲名（⛔ 不需要结束符，长度由 BLE 写决定）
                 *    · ⭐ 空 payload ⇒ ⭐ 回落成 `----`（⭐ 见 `hmi_set_song`）
                 *    · ⭐ 屏上的 `g0` 是**滚动文本** ⇒ 长名字靠它滚
                 * ⚠️ 净化（⭐ 去双引号/控制字符）在 `hmi_set_song()` 里做 ——
                 *    ⭐ 那是**源头**，⛔ 不在这里做（⭐ 否则别的调用方又会漏）。 */
                case 0x22: {
                    char nm[BLE_HMI_CMD_MAX];
                    size_t nn = (len > (uint16_t)(i + 1)) ? (size_t)(len - i - 1) : 0;
                    if (nn >= sizeof(nm)) {
                        nn = sizeof(nm) - 1;
                    }
                    if (nn > 0) {
                        memcpy(nm, val + i + 1, nn);
                    }
                    nm[nn] = '\0';
                    ESP_LOGW(TAG, "CMD 0x22: song name -> \"%s\"", nm);
                    hmi_set_song(nm);            /* ⭐ 净化 + 置 dirty，由 hmi_task 下发 */
                    s_cmd_ok++;
                    i = len;                     /* ⚠️ 正文已消费完 ⇒ 结束本批 */
                    break;
                }
                default:
                    /* ⚠️ 未知命令【计数 + 报出来】，⛔ 不静默吞掉
                     *    （⭐ 静默吞会让人误以为"命令生效了但没反应"） */
                    s_cmd_unknown++;
                    ESP_LOGW(TAG, "CMD 0x%02X: UNKNOWN (ignored, cnt=%lu)",
                             c, (unsigned long)s_cmd_unknown);
                    break;
                }
            }
            if (param->write.need_rsp) {
                esp_ble_gatts_send_response(gatts_if, param->write.conn_id,
                                            param->write.trans_id, ESP_GATT_OK, NULL);
            }
            break;                              /* ⛔ 绝不继续往下当曲谱数据 */
        }

        if (h == s_handle_recv) {
            s_ble_rx_bytes += len;
            hmi_set_state(HMI_ST_LOADING);

            size_t wrote = ble_buf_push(val, len);
            if (wrote < len) {
                s_ble_rx_dropped += (uint32_t)(len - wrote);
                ESP_LOGE(TAG, "ALIGN BUF FULL, dropped %u of %u (total=%lu)",
                         (unsigned)(len - wrote), (unsigned)len,
                         (unsigned long)s_ble_rx_dropped);
                hmi_set_state(HMI_ST_OVERFLOW);
            }
            /* ⭐ 屏上事件计数：已收字节/9 = 已收事件数（⭐ 与守恒等式同口径）
             * 🔴 修了一个真 bug（2026-09-23）：
             *    这里原来【硬编码 total=0】⇒ 屏上一直是 `4820/0`、
             *    进度条和百分比【永远是 0】（⚠️ 恰恰是最该看的两个信息）。
             *    根因：⚠️ ESP32 本来【无从得知总数】—— 协议里没有这个信息。
             * ⭐ 现在：总数由【总数帧】提供（帧头 0x00），存在 s_song_total 里。
             *    ⚠️ 还没收到总数帧时 s_song_total == 0 ⇒ ⭐ 显示层会退化成
             *       "只显示已收数"，⛔ 不会除零（见 hmi.c 的 total>0 判断）。 */
            hmi_set_events(s_song_events_rx, s_song_total);   /* ⭐ 本曲计数，⛔ 不是累计 */
        }

        /* ⚠️ Write Request 需要回响应，否则对端会等超时 */
        if (param->write.need_rsp) {
            esp_ble_gatts_send_response(gatts_if, param->write.conn_id,
                                        param->write.trans_id, ESP_GATT_OK, NULL);
        }
        break;
    }

    case ESP_GATTS_READ_EVT: {
        esp_gatt_rsp_t rsp;
        memset(&rsp, 0, sizeof(rsp));
        rsp.attr_value.handle = param->read.handle;
        /* 2026-10-13 诊断：把客户端【读的每个句柄】都打出来。
         * 背景：实测 PC 连上后只发现 4 个 GATT 强制服务，我们 0xABF0 一个都没有；
         *   而对照设备（另一个 BLE 设备）能正常发现自定义服务
         *   => 问题在板子侧。这条日志能看出客户端【到底问了哪些句柄】：
         *      · 若只读 0x0001~0x0005 一类 => 它压根没扫到我们的服务
         *      · 若读到了 40~49 => 说明扫到了，问题在别处 */
        ESP_LOGI(TAG, "READ_EVT handle=%u conn=%u",
                 (unsigned)param->read.handle, (unsigned)param->read.conn_id);
        /* ⭐⭐ 2026-09-30（B 子集）：**STAT(`0xABF4`) 要回【真实内容】**
         * -----------------------------------------------------------------
         * 🔴 原来这里【无条件**回 0 长度**】⇒ ⚠️ 任何特征读回来都是空串。
         *    对 `0xABF2`/`0xABF1` 无所谓（⭐ 那俩是 notify / write 口），
         *    ⚠️ 但 `0xABF4`(STAT) **是【靠读】取状态的** ⇒ 🔴 读不到就白做。
         * ⭐ 配套改动：`gatt_svc.c` 里 STAT 的响应方式由 `AUTO_RSP`
         *    改为 **`RSP_BY_APP`** ⇒ ⭐ 长度由这里说了算。
         * ⚠️ 必须 `esp_ble_gatts_send_response(...)` 回，⛔ 不能只 set 不回。 */
        if (param->read.handle == s_handle_stat) {
            const uint8_t *st = NULL;
            size_t stn = gatt_get_stat(&st);
            if (st != NULL && stn > 0) {
                if (stn > sizeof(rsp.attr_value.value)) {
                    stn = sizeof(rsp.attr_value.value);   /* ⚠️ 不能超出响应缓冲 */
                }
                memcpy(rsp.attr_value.value, st, stn);
                rsp.attr_value.len = (uint16_t)stn;
            }
            ESP_LOGI(TAG, "READ 0xABF4 -> %u bytes", (unsigned)rsp.attr_value.len);
        } else {
            rsp.attr_value.len = 0;
        }
        esp_ble_gatts_send_response(gatts_if, param->read.conn_id,
                                    param->read.trans_id, ESP_GATT_OK, &rsp);
        break;
    }

    default:
        break;
    }
}

/* ===========================================================================
 * ⭐⭐⭐ 帧头分类 + 过滤（⭐ 这是"总数帧"能工作的关键）
 * ===========================================================================
 * ESP32 是【中转站】，所以【帧头由它来分辨】：
 *
 *   帧头 = 0xA5 且【不是】全 9 字节 0xA5  ⇒ ⭐ 事件帧 ⇒ ✅ 转发给 FPGA
 *   帧头 = 0xA5 且【全 9 字节都是】0xA5  ⇒ ⭐ 复位标记 ⇒ ⛔ 丢弃
 *                                            （⚠️ 与 FPGA 侧同一定义）
 *   帧头 = 0x00                          ⇒ ⭐ 总数帧 ⇒ ⛔ 自己留下，解析
 *   其他帧头                              ⇒ 🔴 未知 ⇒ ⛔ 丢弃 + 计数
 *
 * 🔴 为什么必须在这里过滤（⭐ 而不是让 FPGA 去认）：
 *    ⭐ FPGA 只认 `0xA5` 帧头。⚠️ 任何别的帧头到了它那里
 *      都会 → `hdr_err_cnt_o++`（⚠️ 而它本该是 0，是验收判据）
 *      并且载荷会被当成一个【真事件】⇒ 🔴 弹出随机音符。
 *    ⇒ ⭐ 所以"不是事件帧的东西"必须【在 ESP32 就拦掉】。
 */

/* 统计（⭐ 可观测，K-106 纪律：会出错的东西必须看得见）
 * ⚠️ 这四个变量【定义在文件前部】（见"s_ble_rx_bytes"那一段），
 *    因为 gatts 数据回调也要用 s_song_total。 */

/*
 * ⭐ 判断"这一帧是不是全 0xA5"（⭐ 复位标记）
 * ⚠️ 只看前 9 字节；调用方保证 n >= FRAME_BYTES。
 */
static bool frame_is_all_a5(const uint8_t *p)
{
    for (int i = 0; i < FRAME_BYTES; i++) {
        if (p[i] != FRAME_HDR_EVENT) {
            return false;
        }
    }
    return true;
}

/*
 * ⭐ 解析总数帧：byte 0 = 0x00，byte 1..8 = 大端 uint64 的总事件数
 * ⚠️ 只取低 32 位（⚠️ 本工程事件数远小于 2^32，够用）。
 */
static void frame_parse_total(const uint8_t *p)
{
    uint64_t v = 0;
    for (int i = 1; i < FRAME_BYTES; i++) {
        v = (v << 8) | p[i];
    }
    s_song_total = (uint32_t)v;
    s_total_frames_rx++;
    ESP_LOGI(TAG, "SONG TOTAL = %lu events", (unsigned long)s_song_total);

    /* ⭐⭐ 2026-10-12 修根因：⭐ 总数帧 = 「新曲子的元数据」⇒ 必须把【已收】清零。
     * -------------------------------------------------------------------------
     * 🔴 实测症状：串口屏上显示 **`18704/200`** —— 分子远超分母。
     * ⭐ 根因：`s_song_events_rx`（已收）原来**只在收到「复位帧」时清零**
     *    （见下面 `frame_is_all_a5` 那个分支）。
     *    ⇒ ⚠️ 只要客户端**不反复发复位帧**（⭐ 很多客户端只发一次，
     *       甚至像测试脚本那样一个都不发），"已收"就**跨曲无限累加**
     *    ⇒ 🔴 屏上出现 `18704/200`（= 上一批 18504 + 这一批 200）。
     * ⭐ 正解：⭐ **谁声明"这是新曲子的应到数"，谁就负责把计数器归零** ——
     *    总数帧正是那个声明点 ⇒ 在【这里】清，⛔ 不是只指望复位帧。
     * ⚠️ 两个清零点【都要保留】：复位帧先到（多数客户端）走那条，
     *    总数帧先到 / 只有总数帧的走这条 ⇒ 无论顺序都对。 */
    s_song_events_rx = 0;

    /* ⭐ 屏上：立刻把总数告诉显示层（⚠️ 否则进度条永远是 0） */
    hmi_set_events(s_song_events_rx, s_song_total);   /* ⭐ 本曲计数，⛔ 不是累计 */

#if BLE_MODE == BLE_MODE_B_POOL
    /* ⭐⭐ 模式 B：把"应该收多少帧"告诉水池
     *    🔴 不给它的话，`pool_mark_done()` 无法发现
     *       "PC 发到一半就断了" —— ⚠️ 会把半曲当成整曲播。 */
    pool_set_expected((size_t)s_song_total);
#endif
}

/*
 * ⭐ 逐帧过滤（⭐ 输入必须是 9 的整数倍）
 * 返回【真正要转发给 FPGA 的字节数】—— ⭐ 原地压缩 chunk，非事件帧被摘掉。
 *
 * ⚠️ 为什么原地压缩：避免再开一个 1026 B 的缓冲（⭐ ESP32 内存紧）。
 */
static size_t frame_filter(uint8_t *chunk, size_t n)
{
    size_t out = 0;
    for (size_t off = 0; off + FRAME_BYTES <= n; off += FRAME_BYTES) {
        uint8_t *p = chunk + off;

        if (p[0] == FRAME_HDR_EVENT) {
            if (frame_is_all_a5(p)) {
                s_reset_frames_rx++;          /* ⭐ 复位标记 ⇒ 丢弃 */
                /* ⭐⭐ 2026-10-01（实测修 bug）：复位标记 = 【新曲子开始】
                 *    ⇒ ⭐ 必须把【本曲已收事件数】清零。
                 * 🔴 不这么做的话，屏上的事件计数会**跨曲累加** ——
                 *    实测症状：灌两次 200 帧 ⇒ 屏上显示 `410/200`、
                 *    百分比 `205%`（⭐ 因为 `410*100/200`）。
                 * ⚠️ 根因：原来用的是 `s_ble_rx_bytes`（⭐ **自开机累计**，
                 *    ⛔ 从不复位）⇒ ⚠️ 而总数 `s_song_total` 是**本曲**的
                 *    ⇒ 🔴 **分子是累计、分母是本曲** ⇒ 越灌越离谱。 */
                s_song_events_rx = 0;
                continue;
            }
            /* ⭐ 事件帧 ⇒ 保留（⚠️ 原地压缩），并累加"本曲已收事件数"。
             * ⭐⭐ 2026-10-12 结论（⭐ 试过两种口径后定下来的）：
             * -------------------------------------------------------------
             * `ev` 的定义 = 「**本曲已收事件数**」⇒ 按【收到的事件帧】累加 ✓
             * ⚠️ 曾改成"按真正进池的帧计"（用 `pool_feed` 返回值），
             *    🔴 那是错的：池满时 `ev` 会偏小，与"已收"的定义不符。
             * ⭐ 「本曲」的边界由两个清零点界定：
             *    · 复位帧（下面 `frame_is_all_a5` 分支）
             *    · 总数帧（`frame_parse_total` 里）
             * ⇒ ⭐ 真实客户端每曲发完整整包 ⇒ `ev` 每曲都回到曲谱长度 ✓
             * ⚠️ "只声明一次总数、之后反复灌"是【异常用法】，⛔ 不为它扭曲语义。 */
            if (out != off) {
                memmove(chunk + out, p, FRAME_BYTES);
            }
            out += FRAME_BYTES;
            s_song_events_rx++;               /* ⭐ 本曲已收事件数 +1（⭐ 屏上 t2 用） */
        } else if (p[0] == FRAME_HDR_TOTAL) {
            frame_parse_total(p);             /* ⭐ 总数帧 ⇒ 自己留下 */
        } else {
            s_unknown_frames++;               /* 🔴 未知 ⇒ 丢弃 + 计数 */
            ESP_LOGW(TAG, "unknown frame hdr 0x%02X, dropped (total=%lu)",
                     p[0], (unsigned long)s_unknown_frames);
        }
    }
    /* ⭐⭐ 2026-10-01（实测修 bug）：**在这里**刷新屏上计数，⛔ 不在 BLE 回调里
     * -----------------------------------------------------------------------
     * 🔴 症状：灌 200 帧，⭐ 屏上停在 **`195/200`**（⚠️ 差几个，⛔ 不归位）。
     * ⭐ 根因：`hmi_set_events()` 原来在【BLE 写回调】里调 ——
     *    ⚠️ 而 `s_song_events_rx` 是在**这里**（`frame_filter`）才累加的，
     *    ⭐ 而 `frame_filter` 由 `task_drain` 在**之后**才跑
     *    ⇒ 🔴 **回调里读到的是【上一轮排空后】的旧值** ⇒ ⚠️ 显示**永久落后一拍**。
     * ⭐ 正解：⭐ **在计数【真正变化】的地方刷新**（⭐ 谁改谁负责）。
     *    ⚠️ 这也顺带修掉"最后一拍永远追不上" ——
     *       因为回调只在**还有新数据时**才触发，⭐ 而最后一拍之后就没有新数据了。 */
    /* ⭐⭐ 2026-10-01（实测修 bug）：**在这里**刷新屏上计数，⛔ 不在 BLE 回调里
     * -----------------------------------------------------------------------
     * 🔴 症状：灌 200 帧，⭐ 屏上停在 **`195/200`**（⚠️ 差几个，⛔ 不归位）。
     * ⭐ 根因：`hmi_set_events()` 原来在【BLE 写回调】里调 ——
     *    ⚠️ 而 `s_song_events_rx` 是在**这里**（`frame_filter`）才累加的，
     *    ⭐ 而 `frame_filter` 由 `task_drain` 在**之后**才跑
     *    ⇒ 🔴 **回调里读到的是【上一轮排空后】的旧值** ⇒ ⚠️ 显示**永久落后一拍**。
     * ⭐ 正解：⭐ **在计数【真正变化】的地方刷新**（⭐ 谁改谁负责）。
     *    ⚠️ 这也顺带修掉"最后一拍永远追不上" ——
     *       因为回调只在**还有新数据时**才触发，⭐ 而最后一拍之后就没有新数据了。 */
    if (out > 0) {
        hmi_set_events(s_song_events_rx, s_song_total);
    }
    /* ⭐⭐ 【灌完】→ 屏上显示 `就绪`（⭐ 用户裁定 A：灌完就进就绪）
     * -----------------------------------------------------------------------
     * 🔴 症状（2026-10-01 实测）：⭐ 灌完 200 帧，⭐ 屏上仍是 `灌谱中`。
     * ⭐ 根因：⭐ `HMI_ST_READY` **只有一个 set 点** —— 在【按 STOP】的处理里
     *    ⇒ ⚠️ 而 `hmi.h` 的注释写的是「就绪 —— 灌完，等上板按键起播」
     *    ⇒ 🔴 **注释与代码不一致**（⭐ 见 0.11 第 4 类检查）。
     * ⭐ 正解（改【上游源头】）：⭐ "灌完"的判据就在**这里** ——
     *    ⭐ `s_song_total` 是总数帧给的应到数，`s_song_events_rx` 是实到数
     *    ⇒ ⭐ **实到 == 应到（且应到 > 0）就是灌完**，⛔ 不用另设标志。
     * ⚠️ 只在 `LOADING` 时改：⛔ 不覆盖 `PLAYING` / `DONE` / `断链`
     *    （⭐ 否则重播中途收到重发的帧会把状态打回去）。 */
    if (s_song_total > 0 && s_song_events_rx >= s_song_total
        && hmi_get_state() == HMI_ST_LOADING) {
        ESP_LOGW(TAG, ">>> FEED COMPLETE (%lu/%lu) — ready to start <<<",
                 (unsigned long)s_song_events_rx, (unsigned long)s_song_total);
        hmi_set_state(HMI_ST_READY);
    }
    return out;
}

/* ===========================================================================
 * 任务 1：对齐排空（模式 A -> UART，模式 B -> 水池）
 * =========================================================================== */
static void task_drain(void *arg)
{
    static uint8_t chunk[ALIGN_BUF_CAP];
    (void)arg;

    ESP_LOGI(TAG, "drain task started (mode=%s)",
#if BLE_MODE == BLE_MODE_B_POOL
             "B/pool"
#else
             "A/passthrough"
#endif
            );

    for (;;) {
#if BLE_MODE == BLE_MODE_B_POOL
        /* ⭐⭐ 【自然放完】→ 屏上显示 `播完`
         * -----------------------------------------------------------------
         * ⭐ 判据来自 `pool_take_finished()` —— ⭐ 那是**池自己**在
         *    "游标追上了池内帧数"那个确定点上置的（见 pool.c 的 pool_pump）。
         * ⚠️ 必须用 take 语义：⭐ 本任务是【轮询】的，
         *    若只读不清 ⇒ ⚠️ 每轮都重设一次状态（遥测刷屏）。
         * ⭐ 放在循环【最前】：⛔ 不依赖"有没有新数据"，
         *    ⚠️ 放完那一刻往往已经没有新数据了。 */
        if (pool_take_finished()) {
            ESP_LOGW(TAG, ">>> PLAYBACK FINISHED (pool drained) <<<");
            hmi_set_state(HMI_ST_DONE);
        }
#endif
        size_t n = ble_buf_take_aligned(chunk, sizeof(chunk));
        if (n == 0) {
            /* 🔴 必须【至少 1 tick】—— ⚠️ `pdMS_TO_TICKS(1)` 在 100 Hz 下 = 0
             * ⇒ `vTaskDelay(0)` 不真正让出 ⇒ 本任务（优先级 9）立刻被调度回来
             * ⇒ 忙循环饿死同核 IDLE0 ⇒ 5 s 后 Task watchdog 触发。
             * ⭐ 上机实测于 2026-09-24（COM29），详见 ble_config.h §9b。 */
            vTaskDelay(BLE_DELAY_TICKS_AT_LEAST_1(1));
            continue;
        }
        /* ⭐ n 恒为 9 的整数倍 */

        /* ⭐⭐⭐ 先过滤：摘掉复位标记/未知帧，把总数帧自己留下 */
        size_t fwd = frame_filter(chunk, n);
        if (fwd == 0) {
            continue;                      /* ⭐ 这一批全是非事件帧 */
        }

#if BLE_MODE == BLE_MODE_B_POOL
        /* ⭐⭐ 2026-10-12 关于 `ev`（屏上"已收事件数"）的计数点 —— 最终结论
         * -----------------------------------------------------------------
         * 🔴 先试过"按【真正进池的帧】计"（用 `pool_feed` 的返回值）：
         *    ⭐ 发现它【语义不对】—— 池满时 `ev` 会偏小，
         *    而 `ev` 的定义是"**本曲已收事件数**"（⛔ 不是"已进池数"）。
         * ⭐ 真正的问题不在计数点，而在【"本曲"的边界】：
         *    ⭐ 只有「复位帧」与「总数帧」能界定新曲子 ——
         *    `frame_parse_total()` 收到总数帧时清零（⭐ 见那里），
         *    `frame_filter()` 收到复位帧时清零。
         * ⚠️ 一个"只声明一次总数、之后反复灌"的客户端【本身就是异常的】——
         *    ⭐ 真实客户端（mid2evt -> send_frames_ble）**每曲都发完整整包**，
         *    ⛔ 不该为异常用法扭曲语义。
         * ⭐ 判据（⭐ 与真实客户端同形状）：**每曲发完整整包 ⇒ `ev` 每曲回到曲谱长度**。
         *    📊 实测：灌 3 遍完整整包 ⇒ `ev` = 200 / 200 / 200 ✓ */
        pool_feed(chunk, fwd);
        /* ⚠️ `s_song_events_rx` 在 `frame_filter` 里按【收到的事件帧】累加，
         *    ⛔ 这里不再动它（⭐ 单一写者，避免两个写者打架）。 */
        hmi_set_events(s_song_events_rx, s_song_total);
#else
        int w = uart_write_bytes(BLE_UART_PORT, (const char *)chunk, fwd);
        if (w > 0) {
            s_uart_tx_bytes += w;
        }
#endif
    }
}

/* ===========================================================================
 * ⭐ 起播触发（2026-09-30 新增）
 * ===========================================================================
 * 🔴 为什么需要它：`pool_start()` 原本【零调用】⇒ `s_running` 恒 false
 *    ⇒ **`GPIO17` 永远不发数据**（`sent=` 恒 0）。
 *
 * ⚠️ 起播归属是一个【尚未裁定】的架构问题（方案③ vs 模式B 互斥）——
 *    ⭐ 详见 `files/20-代码/矛盾裁定单-方案3与模式B-20260930.md`。
 *    ⚠️ 本节**不预设裁定结果**，只让"能起播"这件事可测。
 *
 * ⭐ 三种触发（编译期由 `BLE_START_TRIGGER` 选，见 `ble_config.h` §9c）：
 *    · SERIAL —— 从 UART1 RX 收单字符（⭐ 默认，⛔ 无需接线）
 *                ⚠️ 解析点在 `task_uart_to_ble()` 里（⭐ 那个任务已持有读口）
 *    · GPIO   —— 外接按键（⭐ `BLE_BTN_GPIO`；⚠️ **2026-09-30 起是 `GPIO6`，⛔ 不是板载 BOOT 键 `GPIO0`**），⭐ 见 `task_start_trigger()`
 *    · NONE   —— 关闭
 * =========================================================================== */

/* ⭐ 统一的"起播/停/清"动作（⚠️ 触发源共用，逻辑只写一份） */
static void start_action_play(void)
{
    size_t n = pool_frames();
    if (n == 0) {
        /* ⚠️ 池空时起播没意义 —— `pool_start()` 会 `pool_peek_word(0)`，
         *    池空时返回 0 ⇒ `s_t0_tick = 0` ⇒ ⚠️ 不崩但无意义。 */
        ESP_LOGW(TAG, "START ignored: pool is EMPTY (feed frames first)");
        return;
    }
    if (pool_is_running()) {
        ESP_LOGW(TAG, "START ignored: already running (sent=%lu)",
                 (unsigned long)pool_frames_sent());
        return;
    }
    ESP_LOGW(TAG, ">>> START requested (pool=%u frames) <<<", (unsigned)n);
    pool_mark_done();     /* ⭐ 先"封口"：此后池只出不进（⭐ 并做 mismatch 校验） */
    pool_start();         /* ⭐ 真正开闸 */
    hmi_set_state(HMI_ST_PLAYING);
}

static void start_action_stop(void)
{
    ESP_LOGW(TAG, ">>> STOP requested <<<");
    pool_stop();
    hmi_set_state(HMI_ST_READY);
}

static void start_action_reset(void)
{
    ESP_LOGW(TAG, ">>> RESET requested (clear pool) <<<");
    pool_reset();
    hmi_set_state(HMI_ST_IDLE);
}

/* ===========================================================================
 * 任务 2：UART -> BLE（反向通路）+ ⭐ 起播触发（SERIAL 模式）
 * =========================================================================== */
static void task_uart_to_ble(void *arg)
{
    static uint8_t buf[512];
    (void)arg;

    for (;;) {
        int n = uart_read_bytes(BLE_UART_PORT, buf, sizeof(buf), pdMS_TO_TICKS(20));
        if (n > 0) {
        s_uart_rx_bytes += n;

        /* ⭐⭐ 2026-09-30：起播触发（⭐ SERIAL 模式）就在这里处理。
         * 🔴 **为什么放在这个任务里而不是单开一个任务**：
         *    ⚠️ `uart_read_bytes` 【同一个 UART 只能有一个读者】——
         *    开两个任务会【互相偷字节】（⭐ 各拿到一部分，两边都残缺）。
         *    ⭐ 本任务本来就持有这个读口 ⇒ 顺手解析，⛔ 不增加并发风险。
         * ⚠️ 触发字符是【裸 ASCII】（`S`/`X`/`R`），
         *    ⛔ 不是 9 字节帧 ⇒ 与下面的 notify 通路不冲突。 */
#if BLE_START_TRIGGER == BLE_START_TRIG_SERIAL
        for (int i = 0; i < n; i++) {
            uint8_t c = buf[i];
            if (c == 'S' || c == 's') {
                s_trig_cnt++;
                start_action_play();
            } else if (c == 'X' || c == 'x') {
                s_trig_cnt++;
                start_action_stop();
            } else if (c == 'R' || c == 'r') {
                s_trig_cnt++;
                start_action_reset();
            }
        }
#endif

        /* ⭐⭐ 2026-09-30（A 步）：先【无条件入环】
         * -----------------------------------------------------------------
         * 🔴 **入环必须在"是否已连接"判断【之前】** —— 这是本次修复的关键：
         *    ① ⭐ **尽快把 UART 驱动缓冲搬空**（⭐ 那只有 1026 B，见
         *       `ble_config.h:117`）⇒ ⚠️ 只要它被及时搬空，
         *       **就不再因为驱动缓冲溢出而丢字节**（⭐ 那是原来 389 字节的死因）。
         *    ② ⭐ 环是"收到多少"的**唯一账本**（`u_in`）——
         *       ⚠️ 若只在已连接时才入环，未连接期间的字节**凭空消失**
         *          ⇒ 🔴 又变成静默丢，⭐ 那就白做了。
         *    ③ ⚠️ 未连接期间环会积压 ⇒ ⭐ 满了就丢最旧 + **记账**
         *       （⭐ `u_drop` 会涨 ⇒ **看得见**，⛔ 不是无声无息）。
         * 📌 实测（2026-09-30）：环 32 KB 在 PSRAM；⭐ 512 B/次读取
         *    ⇒ ⭐ 正常情况下**一次 push 就装得下**。
         * ⚠️ 生产者与消费者是**同一个任务**（⭐ 硬约束：同一个 UART 只能有一个读者）
         *    ⇒ ⭐ 不引入并发竞争，但环本身仍做了临界区保护（⭐ 以防将来拆分）。 */
        up_ring_push(buf, (size_t)n);
        }   /* ⭐ 收尾：`n > 0` 分支到此为止 */

        /* ⭐⭐ 2026-09-30（A 步 · 关键修正）：**放水必须独立于"有没有新数据"**
         * -----------------------------------------------------------------
         * 🔴 **踩过的坑**：初版把"从环取出来发 notify"写在 `if (n > 0)` 里面
         *    ⇒ ⚠️ **只有收到新 UART 字节时才放水**。
         *    ⭐ 实测症状：蓄水 2000 字节后**接上蓝牙，`u_out` 仍是 0**
         *      —— 🔴 因为连接建立后**没有新字节进来** ⇒ 循环走不到放水那段 ⇒
         *      ⚠️ **存下来的东西永远发不出去**。
         * ⭐ 正解：**放水放在循环体里、与 `n` 无关**（⭐ 见下方），
         *    这样"连接一建立、环里还有存货"就能立刻开始放。 */
        if (s_connected && s_handle_noti != 0 && s_noti_enabled) {
        size_t maxseg = s_mtu > 3 ? (size_t)(s_mtu - 3) : 20;
        size_t pending = (size_t)up_ring_level();
        size_t off = 0;
        while (off < pending) {
            uint8_t tmp[512];
            size_t want = pending - off;
            if (want > sizeof(tmp)) want = sizeof(tmp);
            if (want > maxseg) want = maxseg;
            size_t got = up_ring_peek(tmp, want);
            if (!got) break;
            esp_err_t err = esp_ble_gatts_send_indicate(
                s_gatts_if, s_conn_id, s_handle_noti, got, tmp, false);
            if (err != ESP_OK) {
                s_ble_tx_failed++;
                break;  // Leave this segment and all following bytes for retry.
            }
            up_ring_discard(got);
            s_ble_tx_bytes += got;
            off += got;
            vTaskDelay(BLE_DELAY_TICKS_AT_LEAST_1(BLE_TX_GAP_MS));
        }
    }       /* if (s_connected && s_handle_noti != 0) —— 放水，
             *   ⭐ 注意它【不在】`if (n > 0)` 里面（⭐ 见上方修正说明） */
    }       /* for (;;) */
}

/* ===========================================================================
 * 任务 3：状态打印
 * =========================================================================== */
static void task_status(void *arg)
{
    (void)arg;
#if BLE_MODE != BLE_MODE_B_POOL
    /* ⚠️ 只在模式 A 的打印里用来算增量（模式 B 打的是池水位） */
    uint32_t last_rx = 0;
#endif
    /* ⭐⭐ 2026-10-15：日志周期与 notify 周期不同 ⇒ 用一个累加器分开
     *    · notify = `BLE_STAT_NOTIFY_PERIOD_MS`（300 ms，给客户端做流控）
     *    · 日志   = `BLE_STATUS_PERIOD_MS`（1000 ms，给人看）
     *    ⚠️ 1000 / 300 不是整数 ⇒ ⛔ 不能靠"数够 N 次"来判日志，
     *       必须累加实际毫秒数（⭐ 否则日志周期会漂）✅ */
    uint32_t acc_ms = 0;
    for (;;) {
        /* ⭐⭐ 2026-10-15：**先按 notify 周期推 STAT** ✅
         * 🔴 为什么放在最前面：⭐ 它是本任务存在的**首要理由**（⭐ 见
         *    `stat_notify_now` 与 `s_handle_stat_cccd` 的说明）——
         *    客户端订阅之后**完全不再 readValue()** ⇒ 从根上消除
         *    "读挂住 ⇒ Web Bluetooth 永久卡死" ✗
         * ⚠️ 只在【已订阅】时才重拼内容 —— `cmd_report_status()` 里的
         *    `pool_stats()` 有个 O(帧数) 循环（池 2 MB ⇒ 约 10 ms）
         *    ⇒ ⛔ 没订阅就别白花这个开销 ✅ */
        if (s_connected && s_stat_enabled) {
            cmd_report_status(false);        /* ⭐ 安静模式：⛔ 不打日志 */
            (void)stat_notify_now();
        }
        vTaskDelay(BLE_DELAY_TICKS_AT_LEAST_1(BLE_STAT_NOTIFY_PERIOD_MS));
        acc_ms += BLE_STAT_NOTIFY_PERIOD_MS;
        if (acc_ms < BLE_STATUS_PERIOD_MS) {
            continue;                        /* ⭐ 还没到日志周期 */
        }
        acc_ms = 0;
        uint32_t rx = s_ble_rx_bytes;
#if BLE_MODE == BLE_MODE_B_POOL
        pool_stats_t ps;
        pool_stats(&ps);
        ESP_LOGI(TAG,
                 "ble_rx=%lu | pool=%u/%u (%s) sent=%lu | ovf=%lu late=%lu | "
                 "total=%lu tf=%lu rst=%lu unk=%lu | "
                 "exp=%lu mismatch=%lu clamp=%lu | "
                 /* ⭐ 2026-09-30：把 UART1【接收】字节数与触发字符计数打出来。
                  * 🔴 为什么需要它：起播触发（SERIAL 模式）走的是 UART1 RX
                  *    ⇒ ⚠️ 若"发了 S 却没反应"，光看 `sent=` 分不清是
                  *      【线没接上/波特率不对】还是【固件逻辑没触发】。
                  *    ⭐ 有了 `u_rx=`（收到的总字节）和 `trig=`（识别到的触发）
                  *      就能一刀切开：
                  *        · `u_rx` 不动 ⇒ 🔴 物理层（接线/波特率/共地）
                  *        · `u_rx` 动了但 `trig=0` ⇒ 🔴 引脚对但字符没认出
                  *        · `trig>0` 而 `sent=0` ⇒ 🔴 是起播逻辑的问题
                  * ⚠️ 之前只有模式 A 打 `uart_rx=`（见下方 #else），模式 B 缺。 */
                 "u_rx=%lu trig=%lu | mtu=%u | %s",
                 (unsigned long)rx,
                 (unsigned)ps.frames, (unsigned)ps.capacity_frames,
                 ps.in_psram ? "PSRAM" : "DRAM",
                 (unsigned long)ps.sent_frames,
                 (unsigned long)ps.overflow_frames,
                 (unsigned long)ps.late_ticks_max,
                 (unsigned long)s_song_total,          /* ⭐ 曲谱总事件数 */
                 (unsigned long)s_total_frames_rx,     /* ⭐ 收到的总数帧数 */
                 (unsigned long)s_reset_frames_rx,     /* ⭐ 复位标记帧数 */
                 (unsigned long)s_unknown_frames,      /* 🔴 未知帧头数（应恒为 0） */
                 (unsigned long)ps.expected_frames,    /* ⭐ 应到帧数 */
                 (unsigned long)ps.total_mismatch,     /* 🔴 实收≠应到（应恒为 0） */
                 (unsigned long)ps.tick_clamped_cnt,   /* ⚠️ tick 限流截断次数 */
                 (unsigned long)s_uart_rx_bytes,       /* ⭐ UART1 收到的总字节 */
                 (unsigned long)s_trig_cnt,            /* ⭐ 识别到的触发字符数 */
                 (unsigned)s_mtu,
                 s_connected ? "CONN" : "----");
        /* ⭐⭐ 2026-09-30（A 步）：上行环单独一行 —— ⚠️ 上面那行已经很长了
         * 🔴 为什么必须打这几个数：这是本模块【唯一】的验收手段。
         *    ⭐ 判读表（⭐ 详见 files/20-代码/上行通路缓冲设计-20260930.md §六）：
         *      · ⭐ `u_in` = 2000（灌 2000 字节）⇒ ✅ 环生效
         *        🔴 若 `u_in` 只有 1611 ⇒ ⭐ **缓冲没生效**（⭐ 反向判据）
         *      · 🔴 `u_drop`/`u_drop_ev` **必须 0/0** ⇒ 非 0 说明环满
         *      · ⭐ `hwm` 应 ≤ 灌入量 ⇒ ⚠️ 恒 0 说明环【根本没被用上】
         *      · ⚠️ `level` 稳态应贴近 0 ⇒ 持续增长 = BLE 侧发不动
         *      · ⚠️ `u_rx - u_in` 若不为 0 ⇒ 🔴 读口逻辑有问题（⭐ 正常恒等） */
        up_ring_stats_t us;
        up_ring_stats(&us);
        ESP_LOGI(TAG,
                 "u_in=%lu u_out=%lu | ring=%lu/%lu(%s) hwm=%lu | "
                 "u_drop=%lu/%lu full=%lu | fail=%lu | cmd=%lu/%lu | %s",
                 (unsigned long)us.in, (unsigned long)us.out,
                 (unsigned long)us.level, (unsigned long)us.cap,
                 us.in_psram ? "PSRAM" : "DRAM",
                 (unsigned long)us.hwm,
                 (unsigned long)us.drop_ev, (unsigned long)us.drop,
                 (unsigned long)us.full_hits,
                 (unsigned long)s_ble_tx_failed,
                 /* ⭐ CMD 计数：`认得/不认得`（⭐ 见 s_cmd_ok 的声明处说明） */
                 (unsigned long)s_cmd_ok, (unsigned long)s_cmd_unknown,
                 s_noti_enabled ? "SUB" : "nosub");
#else
        ESP_LOGI(TAG,
                 "ble_rx=%lu uart_tx=%lu | d_rx=%lu | uart_rx=%lu ble_tx=%lu | "
                 "dropped=%lu fail=%lu | buf=%u/%u | mtu=%u | %s",
                 (unsigned long)rx, (unsigned long)s_uart_tx_bytes,
                 (unsigned long)(rx - last_rx),
                 (unsigned long)s_uart_rx_bytes, (unsigned long)s_ble_tx_bytes,
                 (unsigned long)s_ble_rx_dropped, (unsigned long)s_ble_tx_failed,
                 (unsigned)s_cnt, (unsigned)ALIGN_BUF_CAP,
                 (unsigned)s_mtu,
                 s_connected ? "CONN" : "----");
#endif
#if BLE_MODE != BLE_MODE_B_POOL
        last_rx = rx;
#endif
    }
}

/* ===========================================================================
 * 起播触发的 GPIO 变体（⭐ 仅 `BLE_START_TRIGGER == GPIO` 时编译）
 * ===========================================================================
 * ⚠️ 用**外接按键**（⭐ 低有效）：⭐ 引脚 = `BLE_BTN_GPIO`
 *    （⚠️ **2026-09-30 起是 `GPIO6`**，🔴 ⛔ **不是**板载 BOOT 键 `GPIO0`）。
 * ⭐ 轮询 + 消抖（⛔ 不用中断，⭐ 省事且够用）。
 * ⚠️ `BLE_BTN_POLL_MS` / `BLE_BTN_DEBOUNCE_MS` 都 ≥ 10 ms，
 *    ⛔ 不会被 `pdMS_TO_TICKS` 塌成 0（⭐ 见 ble_config.h §9b 的教训）。
 * =========================================================================== */
#if BLE_START_TRIGGER == BLE_START_TRIG_GPIO
void task_start_trigger(void *arg)
{
    (void)arg;
    int stable = 1;
    int low_ms = 0;

    ESP_LOGI(TAG, "start trigger = GPIO%d (BOOT button, active low)",
             BLE_BTN_GPIO);

    gpio_config_t io = {
        .pin_bit_mask = (1ULL << BLE_BTN_GPIO),
        .mode         = GPIO_MODE_INPUT,
        .pull_up_en   = GPIO_PULLUP_ENABLE,     /* ⭐ 板载键低有效 */
        .pull_down_en = GPIO_PULLDOWN_DISABLE,
        .intr_type    = GPIO_INTR_DISABLE,      /* ⭐ 轮询，⛔ 不用中断 */
    };
    ESP_ERROR_CHECK(gpio_config(&io));

    for (;;) {
        int now = gpio_get_level(BLE_BTN_GPIO);
        if (now == 0) {
            if (low_ms < BLE_BTN_DEBOUNCE_MS) {
                low_ms += BLE_BTN_POLL_MS;
            } else if (stable == 1) {
                stable = 0;                     /* ⭐ 消抖后确认"按下"边沿 */
                ESP_LOGI(TAG, "button pressed");
                start_action_play();
            }
        } else {
            low_ms = 0;
            stable = 1;
        }
        vTaskDelay(BLE_DELAY_TICKS_AT_LEAST_1(BLE_BTN_POLL_MS));
    }
}
#endif /* BLE_START_TRIGGER == BLE_START_TRIG_GPIO */

/* ===========================================================================
 * 入口
 * =========================================================================== */
void app_main(void)
{
    ESP_LOGI(TAG, "=== ESP32-S3 BLE <-> UART bridge ===");
    ESP_LOGI(TAG, "mode = %s",
#if BLE_MODE == BLE_MODE_B_POOL
             "B / POOL (buffer whole score, self-paced)"
#else
             "A / PASSTHROUGH (relay as they arrive)"
#endif
            );
    ESP_LOGI(TAG, "uart=%d baud=%d tx=GPIO%d rx=GPIO%d frame=%dB name=%s",
             BLE_UART_PORT, BLE_BAUD, BLE_PIN_UART_TX, BLE_PIN_UART_RX,
             FRAME_BYTES, BLE_DEV_NAME);

#if WS2812_ENABLE || WS2812_CLEAR_ON_BOOT || BLE_LED_ENABLE
    /* ⭐ 连接指示灯（⭐ 尽早初始化 —— ⚠️ 放在 NVS/蓝牙之前，
     *    这样"灯没亮"能立刻区分成"固件没跑起来"而不是"蓝牙没连上"） */
    ind_init();
#endif

    /* NVS（蓝牙栈要求） */
    esp_err_t err = nvs_flash_init();
    if (err == ESP_ERR_NVS_NO_FREE_PAGES || err == ESP_ERR_NVS_NEW_VERSION_FOUND) {
        ESP_ERROR_CHECK(nvs_flash_erase());
        err = nvs_flash_init();
    }
    ESP_ERROR_CHECK(err);

    /*
     * ⚠️ S3 只有 BLE ⇒ 控制器模式必须是 BLE_ONLY（或 BTDM）。
     *    🔴 这里【必须】在 sdkconfig.defaults 里显式设
     *       CONFIG_BTDM_CTRL_MODE_BLE_ONLY=y（⚠️ SPP 版踩过"默认不是它"的坑）。
     */
    esp_bt_controller_config_t bt_cfg = BT_CONTROLLER_INIT_CONFIG_DEFAULT();

    /* 🔴🔴 2026-09-24 上机实测：缺了这一步，广播使能被控制器拒绝！
     *   症状：E BT_BTM: btm_ble_write_adv_enable_complete failed
     *         E blebridge: adv start failed: 0xD
     *   ⭐ 定位：与 IDF 官方例子 ble_ibeacon 对照发现，
     *      官方在 controller_init 【之前】先调用了：
     *          esp_bt_controller_mem_release(ESP_BT_MODE_CLASSIC_BT);
     *      ⭐ S3 硬件【只有 BLE】，经典蓝牙的内存若不放，
     *         控制器可用内存偏紧 ⇒ 广播这类"活动"申请资源失败。
     *   ⚠️ 官方【每一个】BLE 例子都有这一行，我们漏了。
     *   ⚠️ 必须在 esp_bt_controller_init() 之前调用。 */
    ESP_ERROR_CHECK(esp_bt_controller_mem_release(ESP_BT_MODE_CLASSIC_BT));

    ESP_ERROR_CHECK(esp_bt_controller_init(&bt_cfg));
    ESP_ERROR_CHECK(esp_bt_controller_enable(ESP_BT_MODE_BLE));
    ESP_ERROR_CHECK(esp_bluedroid_init());
    ESP_ERROR_CHECK(esp_bluedroid_enable());

    ESP_ERROR_CHECK(uart_fpga_init());

    /* ⭐ 串口屏（UART2）—— ⚠️ 放在蓝牙之后，别抢启动时间 */
    hmi_init();

    /* ⭐ 注册服务（属性表在 gatt_svc.c；⭐ 回调只有这一个） */
    ESP_ERROR_CHECK(esp_ble_gatts_register_callback(gatts_event_handler));
    ESP_ERROR_CHECK(esp_ble_gap_register_callback(gap_event_handler));
    ESP_ERROR_CHECK(esp_ble_gatts_app_register(0));

    xTaskCreate(task_drain,        "drain", 4096, NULL, BLE_TASK_PRIO_DRAIN, NULL);
    xTaskCreate(task_uart_to_ble,  "u2ble", 4096, NULL, BLE_TASK_PRIO_UART_RX, NULL);
    xTaskCreate(task_status,       "stat",  3072, NULL, BLE_TASK_PRIO_STATUS, NULL);

    /* ⭐⭐ 2026-09-30（A 步）：上行环形缓冲初始化
     * 🔴 为什么需要它：反向通路原来**无缓冲** ⇒ 实测灌 2000 字节只收到 1611
     *    （🔴 丢 389 且**无任何报错**）。
     * ⚠️ 分配失败**不 abort** —— ⭐ 退化为原来的"直通 + 慢"行为，
     *    ⭐ 但那时 `u_in` 会停在 0、`u_drop` 也不动 ⇒ ⚠️ 一眼能看出没生效。
     * ⭐ 必须在 `task_uart_to_ble` 启动**之前**初始化（⭐ 否则会 push 到空环）。 */
    up_ring_init();

#if BLE_MODE == BLE_MODE_B_POOL
    /* ⭐ 开机初始化：⭐ 这里【允许】直接调 `pool_reset()`
     * -----------------------------------------------------------------
     * ⚠️ 理由：⭐ 此刻**屏还没初始化**（`hmi_init()` 在任务里才跑），
     *    而 `hmi_set_state()` 只是写结构体字段 ⇒ ⭐ 调了也是空转，
     *    ⚠️ 反而容易让人误以为"状态已经推给屏了"。
     * ⭐ 屏上状态本来就从 `HMI_ST_IDLE` 起（见 `hmi.c` 的 `hmi_init`）⇒
     *    ⭐ **不需要**在这里再推一次。
     * 📌 `ALLOW-DIRECT-POOL-CALL` 是给 `wrappers_check.py` 的**显式豁免标记**
     *    —— ⭐ 让"唯一一处例外"在代码里**看得见**，⛔ 不是靠记性。 */
    pool_reset();   /* ALLOW-DIRECT-POOL-CALL: 开机初始化，屏尚未就绪 */
    xTaskCreate(task_pool_pump, "pump", 4096, NULL, BLE_TASK_PRIO_DRAIN, NULL);
    ESP_LOGW(TAG, "MODE B (pool): feed whole score first.");

    /* ⭐ 起播触发（2026-09-30 新增）
     * ⚠️ 只有 GPIO 模式需要独立任务 ——
     *    SERIAL 模式的解析点在 `task_uart_to_ble()` 里
     *    （⭐ 那个任务已持有 UART 读口；🔴 开两个读者会【互相偷字节】）。 */
#if BLE_START_TRIGGER == BLE_START_TRIG_GPIO
    xTaskCreate(task_start_trigger, "start", 3072, NULL, BLE_TASK_PRIO_STATUS, NULL);
    ESP_LOGW(TAG, "START trigger = GPIO%d (BOOT button): press to start", BLE_BTN_GPIO);
#elif BLE_START_TRIGGER == BLE_START_TRIG_SERIAL
    ESP_LOGW(TAG, "START trigger = SERIAL: send 'S' to UART%d RX (GPIO%d) to start",
             BLE_UART_PORT, BLE_PIN_UART_RX);
#else
    ESP_LOGW(TAG, "START trigger = NONE: pool_start() will never be called");
#endif
#endif
    ESP_LOGI(TAG, "ready. scan for \"%s\" from phone/PC.", BLE_DEV_NAME);
}
