hokuu1102/Gowin2026-PolySynth/esp32/ble/main/ble_config.h

/*
 * ble_config.h -- ESP32-S3 BLE 透传桥 · 可配置项
 * ============================================================================
 * 项目：FPGA2026 · ESP32 通路（⭐ S3 / BLE 版）
 *
 * ⚠️ 本文件是【唯一】需要按现场改的地方。
 *
 * ============================================================================
 * 🔴 与 SPP 版（esp32/bridge/）的关键差异 —— ⛔ 不要混用两者的假设
 * ============================================================================
 *  | | SPP 版（初代 ESP32）    | ⭐ 本版（ESP32-S3）        |
 *  |---|---|---|
 *  | 蓝牙     | 经典 BR/EDR + SPP  | 🔴 **只有 BLE**（S3 无 BR/EDR） |
 *  | PC 侧    | ⭐ 配对后是个 **COM 口** | 🔴 **不是 COM 口** ⇒ `evt2uart.py` **不能直接用** |
 *  | 手机侧   | 通用"蓝牙串口助手"      | ⭐ 需 **BLE 终端 App**（支持自定义 UUID 的） |
 *  | PSRAM    | ⚠️ 买不到带 PSRAM 的板 | ⭐ **有**（S3 那块）⇒ 水池可以放整曲 |
 *
 * ⭐ 为什么会有这一版：⚠️ 初代 ESP32 + PSRAM 的开发板买不到，
 *    而手上那块 S3 【有 PSRAM】 ⇒ 用 S3 走 BLE 换取大水池。
 *    ⚠️ 代价：PC 侧生态不如 SPP 方便（见上表）。
 * ============================================================================
 */
#ifndef BLE_CONFIG_H
#define BLE_CONFIG_H

/* ---------------------------------------------------------------------------
 * 1. 帧格式（⭐ 冻结契约，⛔ 别改 —— 与 SPP 版逐位一致）
 * ---------------------------------------------------------------------------
 * byte 0    : 0xA5          帧头（固定魔数）
 * byte 1..8 : 64 bit 事件   大端
 *
 * ⭐⭐⭐ 三种 9 字节块（ESP32 靠【帧头】区分，⛔ 不是靠位置）
 * ---------------------------------------------------------------------------
 *  ① 帧头 = 0xA5  ⇒ ⭐ **事件帧** ⇒ ✅ **转发给 FPGA**
 *  ② 帧头 = 0x00  ⇒ ⭐ **总数帧** ⇒ ⛔ **ESP32 自己留下**（见下）
 *  ③ 全 9 字节 = 0xA5 ⇒ ⭐ **复位标记** ⇒ ⛔ **丢弃**（⚠️ 与 FPGA 侧同一定义）
 *
 * 🔴 为什么总数帧用 `0x00` 开头：
 *    ⭐ 事件帧帧头是 `0xA5` ⇒ ⛔ **永不撞车**（⭐ 比"约定某个位置"可靠）。
 *
 * 🔴 为什么总数帧也是 **9 字节**：
 *    ⭐ 这样 ESP32 的 **9N 对齐逻辑一行都不用改** ——
 *      它照样按 9 字节切，⭐ 只是看帧头决定"转发还是自己留下"。
 */
#define FRAME_BYTES          9

/* 事件帧帧头（⭐ 冻结值，与 FPGA 侧 `evt_uart_rx.v` 一致） */
#define FRAME_HDR_EVENT      0xA5u

/* ⭐ 总数帧帧头（ESP32 内部约定；⛔ FPGA 永远看不到它） */
#define FRAME_HDR_TOTAL      0x00u

/* ---------------------------------------------------------------------------
 * 2. 波特率（⭐ 必须与 FPGA 侧一致）
 * ---------------------------------------------------------------------------
 * ⭐ 现值 500,000（500 kbps）
 *
 * 🔴🔴 2026-09-30 更正（⭐ 这条曾经写错，务必看清）：
 *     ⚠️ 本节原来写"目标 1 Mbps、FPGA 侧现值仍是 115200" —— 🔴 【两句都过时了】。
 *
 *     ⭐ 真相（⭐ 已拉 `FPGA2026` 主仓库核实，⛔ 不是看本仓库的 rtl 快照）：
 *       · 🔴 **FPGA 侧【2026-09-24 就降到了 500 k】**
 *         —— `FPGA2026/rtl/top.v:682/709/765/809/914` 全是 `100` / `500_000`
 *         —— 注释原文：`// uart_rx #(.BAUD_DIV(100)) // 🔴 2026-09-24：from 1 Mbps → 500 kbps`
 *       · ⭐ 用户在真机上实测：**1 Mbps【经常出问题】，500 k【比较稳定】**
 *         （⭐ 与 `rtl/w3c/uart_rx.v:36-40` 那条 CP2102 实证一致）
 *
 *     🔴 **⇒ ESP32 侧原来还是 1 Mbps ⇒ 两侧【不匹配】**
 *        ⇒ ⚠️ 正是 `evt_uart_rx.v:73` 警告的「**静默收到乱码**」（⛔ 不报错）
 *        ⇒ ⭐ **所以这里必须改成 500000。**
 *
 * ⭐ 为什么 500 k 不影响性能（⭐ 核算过，⛔ 不是估计）：
 *     · FPGA 消费只有 **~69.5 事件/s**（最密曲 @168 BPM，见 `pool.c:19`）
 *     · 放水需求 = 69.5 × 9 B = **626 B/s**
 *     · 500 kbps 提供 50,000 B/s ⇒ ⭐ **余量 80 倍**
 *     · ⚠️ 且波特率减半 ⇒ 灌满 FPGA 的 8 KB 缓冲从 82 ms 变 **164 ms**
 *       ⇒ ⭐ **溢出风险【降低】**（⭐ 正符合 `pool.c:24`「宁可饿着，不可撑着」）
 *     · ⭐ 而**整曲灌谱走 BLE**（`pool.c:9`）⛔ **不经 UART** ⇒ 降档**不影响灌谱速度**
 *
 * ⚠️ 两侧【必须同时】改（⭐ `evt_uart_rx.v:73`：不匹配会**静默乱码**）。
 * ⚠️ 可用 `-DBLE_BAUD=...` 覆盖（⭐ 见下方 `#ifndef`）。
 */
#ifndef BLE_BAUD
#define BLE_BAUD             500000
#endif

/* ---------------------------------------------------------------------------
 * 3. 引脚（给 FPGA 的 UART2）
 * ---------------------------------------------------------------------------
 * ⚠️ 必须【交叉接】：
 *      ESP32 TX(GPIO17) -> FPGA UART2_RX(G22)
 *      ESP32 RX(GPIO18) <- FPGA UART2_TX(G21)
 *
 * 🔴 GPIO43/44 是 U0 日志口，⛔ 不要占用。
 * 🔴🔴 【S3 特有】若模组带 PSRAM（如 ESP32-S3-WROOM-1-N16R8），
 *      **GPIO35/36/37 被八线 PSRAM 占用**，且 **GPIO26~32 也常用于 flash/PSRAM**
 *      ⇒ ⭐ 改引脚前必须对照具体模组的 datasheet。
 *      ⭐ 这里选 GPIO17/18 —— 在 S3 上是安全的通用 IO（⛔ 不是 USB 脚）。
 *      ⚠️ GPIO19/20 是 S3 的原生 USB（D-/D+），⛔ 不要当普通串口用。
 *      🔴 GPIO38/48 是【板载 RGB LED】，⚠️ 驱动它们会让板子亮灯。
 */
#define BLE_UART_PORT        UART_NUM_1
#define BLE_PIN_UART_TX      17
#define BLE_PIN_UART_RX      18

/* 日志口（UART0）—— ⚠️ S3 上默认走 GPIO43/44 */
#define BLE_LOG_UART_PORT    UART_NUM_0
#define BLE_PIN_LOG_TX       43
#define BLE_PIN_LOG_RX       44

/* ---------------------------------------------------------------------------
 * 4. UART 缓冲
 * ---------------------------------------------------------------------------
 * ⚠️ TX 缓冲取 9 的整数倍（1026 = 9×114），使块边界天然落在帧边界上。
 */
#define BLE_UART_TX_BUF      (FRAME_BYTES * 114)   /* 1026 B */
/*
 * 🔴🔴 RX 缓冲（⭐ 2026-09-30 实测放大）—— **上行丢字节的真正瓶颈在这里**
 * ---------------------------------------------------------------------------
 * ⭐ 原来也是 1026 B，⚠️ 而实测：往 `GPIO18` 灌 **2000 字节** ⇒
 *    🔴 **只收到 1613**（丢 387），⚠️ **且没有任何报错**。
 *
 * 🔴 根因（⭐ 与"上行环形缓冲"是【两回事】，两个都要）：
 *    · `task_uart_to_ble` 用 `uart_read_bytes(port, buf, 512, 20ms)`
 *      ⇒ ⚠️ 它【要等满 512 字节才返回】（或 20 ms 超时）
 *    · 512 B @50 KB/s = **10.2 ms** 才凑齐
 *    · 而 2000 B 全部到达只要 **40 ms**
 *    ⇒ ⚠️ 读的节奏（4×10.2 = 41 ms）与到的节奏（40 ms）**几乎相同**，
 *      ⭐ 任何一次调度延迟，**驱动缓冲（1026 B）就先溢出** ⇒ 🔴 丢。
 *
 * ⭐ 为什么应用层环【救不了】这一段：⭐ 环在**驱动缓冲之后** ——
 *    ⚠️ 字节在进环之前就已经被驱动丢掉了。
 *    📌 实测佐证：环 `u_drop=0/0`、`ring=1613/32768`（⭐ 才 5% 满）
 *      ⇒ 🔴 **环没满、没丢，丢的在上游**。
 *
 * ⭐ 取值：**8192 B**（= 8 KB）
 *    · ⭐ 覆盖 2000 字节突发**绰绰有余**（余量 4 倍）
 *    · ⚠️ 落在**内部 DRAM**（⛔ 不是 PSRAM —— UART 驱动要求 DMA 可达内存）
 *      ⇒ ⚠️ 代价是 8 KB DRAM；⭐ 实测 DRAM 尚有富余（⭐ 下行池已在 PSRAM）
 *    ⚠️ 注意：⛔ **不必是 9 的倍数** —— 那是【TX】的要求（⭐ 让块边界落在帧边界），
 *       ⭐ RX 只是接收缓冲，⭐ 不参与"按帧写出"。
 */
#define BLE_UART_RX_BUF      (8 * 1024)            /* 8192 B，见上方说明 */

/* ---------------------------------------------------------------------------
 * 5. ⭐ BLE 参数
 * ---------------------------------------------------------------------------
 * ⚠️ 设备名：手机/PC 靠它找设备。⛔ 不要写含人名的字符串。
 *
 * 🔴🔴 2026-10-13 改名（`-Synth` -> `-Synth2`）—— 这不是随意改，是【绕开
 *   Windows 的 GATT 缓存】：
 *   实测症状：板子固件完全正常（日志里 `attr table created OK`、
 *     `0xABF1`~`0xABF4` 全部注册、`service started`），但 PC 连上后
 *     只能发现 【4 个标准 GATT 特征】，我们自己的一个都没有
 *     => `BleakCharacteristicNotFoundError`（0xABF3 not found）。
 *   ⭐ 根因：Windows 按【MAC 地址】缓存服务列表，不信板子的实际 GATT。
 *     板子复位、重烧固件都无效（试过，都还是 4 个）——
 *     因为地址没变。
 *   ⭐ 换名字会让 Windows 当成【新设备】，缓存自然失效。
 *   📌 若将来又要清缓存：再改一次名字（`-Synth3`）即可，
 *     ⛔ 不必动注册表（那里也没有 GATT 缓存，实测只存了设备名/指纹）。
 */
#define BLE_DEV_NAME         "FPGA2026-Synth2"

/*
 * 🔴 GATT UUID —— ⭐ **照抄 ESP-IDF 官方 `ble_spp_server` 示例**
 *    来源（⭐ 我实际拉取了源码核对，⛔ 不是凭印象）：
 *      esp-iot-solution/examples/bluetooth/ble_conn_mgr/ble_spp/spp_server/main/app_main.c
 *
 *    官方原文定义：
 *        #define BLE_SVC_SPP_UUID16      0xABF0   // ⭐ 服务
 *        #define BLE_SVC_SPP_CHR_UUID16  0xABF1   // ⭐ 特征
 *
 *    ⚠️⚠️ 这里踩过一个【我自己的认知错误】，⚠️ 记下来免得后人再错：
 *       我原以为"服务是 128 位 vendor UUID、0xABF1 挂在它下面"。
 *       🔴 实际官方**服务和特征都是【16 位】标准 UUID**：
 *           服务   = 0xABF0
 *           接收   = 0xABF1   （对端写数据进来）
 *           通知   = 0xABF2   （我们发出去）
 *           命令   = 0xABF3
 *           状态   = 0xABF4
 *       ⭐ 用 16 位反而【更好】—— 现成 BLE 终端 App 填 UUID 时更省事。
 *
 *    ⚠️ 另一条：官方示例走的是 `esp_ble_conn_mgr` 高层组件，
 *       而我们用**原生 Bluedroid API** ⇒ ⛔ **只能照抄 UUID 定义，
 *       不能照抄它的调用方式**（两者 API 完全不同）。
 */
#define BLE_SVC_UUID16        0xABF0
#define BLE_CHR_RECV_UUID16   0xABF1   /* ⭐ 对端写这里 */
#define BLE_CHR_NOTI_UUID16   0xABF2   /* ⭐ 我们 notify 这里 */
#define BLE_CHR_CMD_UUID16    0xABF3
#define BLE_CHR_STAT_UUID16   0xABF4

/*
 * ⚠️ MTU：⚠️ 默认 ATT MTU = 23（有效载荷仅 20 字节）。
 *    整曲 104 KB 若按 20 字节一包发 ⇒ **5200 多包** ⇒ ⚠️ 慢且易错。
 *    ⭐ 所以必须在对端连接后【协商更大 MTU】。
 *    ⚠️ 但能协商到多少由【对端】决定：
 *        · 手机 App 常见 247 / 512
 *        · Windows 常给 517 或 185
 *    ⭐ 这里设"期望值"，实际以协商结果为准（⚠️ 会在日志里打出来）。
 */
#define BLE_PREFERRED_MTU    517

/* ---------------------------------------------------------------------------
 * 6. ⭐ 转发模式（与 SPP 版同构）
 * ---------------------------------------------------------------------------
 *   模式 A：纯透传   —— PC/手机 限速发，ESP32 收到就转（9N 对齐）
 *   模式 B：二级水池 —— ESP32 缓存整曲 + 自己按谱子时间放水
 *
 * ⚠️ 两模式共用同一套 9N 对齐与写 UART 路径。
 *
 * ⭐ 默认改为 **模式 B**（2026-09-23 用户拍板）：
 *    ⭐ 理由：S3 那块**有 PSRAM**，水池放得下整曲（104.3 KB）⇒
 *           ⭐ **PC 侧零限速**（一口气灌完即可），⭐ 节奏由 ESP32 自己管。
 *    ⚠️ 要用模式 A：`idf.py -DBLE_MODE=0 build`
 */
#define BLE_MODE_A_PASSTHROUGH   0
#define BLE_MODE_B_POOL          1

#ifndef BLE_MODE
#define BLE_MODE             BLE_MODE_B_POOL      /* ⭐ 默认模式 B */
#endif

/* ---------------------------------------------------------------------------
 * 7. 任务优先级与状态打印
 * ---------------------------------------------------------------------------
 */
#define BLE_TASK_PRIO_DRAIN     9
#define BLE_TASK_PRIO_UART_RX   8
#define BLE_TASK_PRIO_STATUS    4
#define BLE_STATUS_PERIOD_MS    1000

/* ⭐⭐ 2026-10-15：`0xABF4`(STAT) 的**周期性 notify** 周期
 * ---------------------------------------------------------------------------
 * 🔴 为什么必须做（出处：ESP32侧需求-STAT周期性notify-20261014.md）：
 *    `0xABF4` 的属性位本来就含 `NOTIFY`，但固件**从不发** ⇒ 客户端只能
 *    `readValue()`。⚠️ 而 ESP32 在**灌谱/播放期间忙于往 FPGA 转发**，
 *    读回调得不到及时服务 ⇒ 🔴 客户端 `readValue()` 挂住。
 *    而 Web Bluetooth **无法取消**已发出的操作 ⇒ ⚠️ 浏览器认为"还有一个
 *    操作在飞" ⇒ 之后每个操作都报 `GATT operation already in progress`
 *    ⇒ 🔴 **起播/停止/清池全部失效，只能断开重连**。
 *    ⭐ 根治办法 = 客户端改成【订阅 notify】、⛔ 不再主动读
 *    ⇒ 没有读，就没有"读不回来"。
 *
 * 📌 周期取 300 ms：需求建议 200~500 ms（状态变化本来就慢）。
 * ⚠️ 与 `BLE_STATUS_PERIOD_MS`（日志）**分开** —— 日志 1 s 是给人看的，
 *    notify 300 ms 是给流控用的（ESP32 侧要用 `pool=N/CAP` 做真流控，
 *    见需求 §五.2）⇒ 两者节奏不同，⛔ 不要合成一个。
 * 🔴 开销：`cmd_report_status()` 里 `pool_stats()` 有个 O(帧数) 求 `total_tick`
 *    的循环（池现在 2 MB ⇒ 约 10 ms/次）⇒ 300 ms 周期 ≈ **3% CPU**
 *    ⚠️ 若实测不可接受，改大这个数即可（客户端能适配）。 */
/* 🔴🔴 2026-10-15：300 -> 1500 ms（实测定位，用户数据）。
 * 现象：加了 300 ms notify 之后，灌谱从 20~30 KB/s 掉到 3~7 KB/s。
 *   实测遥测：我方等待占比 90~95%，而 ESP32 收速只有 1.7~6.9 KB/s
 *   ⇒ ⭐ 不是我方节流，是【ESP32 收得慢】。
 * 机制：esp_ble_gatts_send_indicate 每 300 ms 排一个 ~395 B 的通知，
 *   占用蓝牙控制器的 TX 缓冲；而 ESP32 的 TX/RX 共用同一小缓冲池
 *   ⇒ TX 排队把缓冲占住 ⇒ LL 层的 ACK 发不出去 ⇒ 对端重传 ⇒ 接收吞吐崩。
 * ⚠️ 已排除：GATT 写回调不阻塞（s_ble_rx_bytes += len 后直接 ble_buf_push）、
 *   环没满（ble.drop=0）、池没满（ovf=0）、泵任务在上传期不跑。
 * ⭐ 1500 ms 够用：状态变化本来就慢，而流控靠在途量不靠刷新率
 *   （我方窗口已同步放大到 64 KB 补偿）。
 * 📌 若还想更快：这个数可以再拉长（我方流控能适配）。 */
#define BLE_STAT_NOTIFY_PERIOD_MS  100

/* ---------------------------------------------------------------------------
 * 8. 反向通路（UART -> BLE）
 * ---------------------------------------------------------------------------
 */
#define BLE_TX_CHUNK         244      /* ⚠️ 不超过协商 MTU-3 */
#define BLE_TX_GAP_MS        2

/* ===========================================================================
 * 9. ⚠️ 水池参数（⭐ 无条件定义 —— ⛔ 不要放回 #if 里面）
 * ===========================================================================
 * 🔴 这里在 SPP 版踩过真 bug：宏被 `#if BLE_MODE==...` 挡住，而 pool.c 是
 *    【无条件编译】的 ⇒ 模式 A 下编不过（'undeclared'）。⇒ 一律无条件定义。
 */

/*
 * ⭐ 水池【期望】容量。
 *
 * ⭐ 本版（S3 + PSRAM）比 SPP 版的优势就在这里：
 *    SPP 版：内部 DRAM 只剩 77.8 KB < 整曲 104.3 KB ⇒ 🔴 装不下整曲
 *    本  版：⭐ **有 PSRAM（S3 那块）** ⇒ 整曲轻松放下
 *
 * ⚠️ 实际拿到多少由 pool.c 的 pool_alloc() 决定（优先 PSRAM，退化内部 DRAM）。
 */
/* ⭐⭐ 2026-10-14 从 160 KB 提到 2 MB（用户实测定位）。
 * 🔴 原来 160 KB = 18204 帧（按 104.3 KB 的谱设计），
 *    而用户谱面 23563 帧 => 溢出不可避免（实测 STAT: pool=0/18204, ovf=244 起）。
 * ⭐ ESP32 存整曲、按时间放水（FPGA 只吃它喂出来的），
 *    而模组 N16R8 有 8 MB PSRAM，pool_alloc() 本来就优先 PSRAM。
 *    2 MB = 233016 帧 ≈ 10 倍余量。实测 ovf 归零 ✅
 * ⚠️ 唯一代价：pool_stats() 里那个 O(帧数) 循环（遍历的是池里实际帧数，
 *    ⛔ 不是容量）=> 容量不影响热路径开销。 */
#define BLE_POOL_BYTES       (2 * 1024 * 1024)   /* ⭐ 2 MB ≈ 233016 帧（PSRAM） */

/*
 * ⭐ 提前量（tick）—— 与 SPP 版同一取值与依据。
 *
 *   FPGA 缓冲 8 KB = 1024 事件（🔵 2026-09-23 FPGA 侧已采纳）。
 *   最密曲 夜洋风景 = 99.3 事件/小节，PPQN=960
 *   => 1024 事件 ≈ 39,600 tick
 *   ⇒ ⭐ 取 20,000 tick（≈5.2 小节 ≈ 517 事件）—— 占 FPGA 缓冲约一半，留一半余量。
 *
 *   🔴 太大 ⇒ FPGA 缓冲溢出（静默丢）；⚠️ 太小 ⇒ 一卡就 underrun（掉音）
 */
#define BLE_POOL_LEAD_TICKS      20000u

/* 2026-10-14 新增：提前量的【下限】，以及 FPGA 侧缓冲的水位常量。
 *
 * 背景：提前量由固定值改成了【按谱面密度动态算】（见 pool.c 的
 *   pool_compute_lead_ticks）。算出的值夹在 [MIN, LEAD_TICKS] 之间。
 *   · LEAD_TICKS（20000）= 上限，按最密谱面定的，别超过
 *   · MIN = 下限，⚠️ 再稀的谱面也得留一点，否则 BLE 一抖就 underrun
 */
#define BLE_POOL_LEAD_MIN_TICKS   1200u    /* 0.625 秒 @120BPM/960PPQN */

/* 抗一次 BLE 停顿所需的【音乐时间】（秒）。
 * ⭐ 为什么提前量基本就是个常数：
 *    提前量 = "抗住一次停顿所需的事件存货" 对应的音乐时间，
 *    而"存货 = 该停顿期间本会消耗的事件数" => 两者恰好抵消
 *    => 结果与谱面密度【无关】。
 * ⚠️ 0.1 秒是【我方估的】（BLE 连接间隔通常 << 100 ms），
 *    ⛔ 不是 FPGA 侧给的。若要更稳，应收紧到实测的最大停顿。
 * 📌 详见 esp32/tools/_lead_model_check.py（三版模型的推演）。 */
#define BLE_POOL_STALL_SEC        0.10f

/* 音乐速率（tick/s）@120BPM / PPQN 960 —— 用于把"秒"换算成 tick。
 * ⚠️ 若将来支持换速，这个值会随 tempo 事件变；本处的提前量只在
 *    起播时算一次，故用默认速率是合理的（换速时会重锚，不影响提前量）。 */
#define BLE_POOL_TICKS_PER_SEC    1920.0f

/* FPGA 侧事件缓冲的水位（权威出处：FPGA 线 2026-10-14 答复 §二，
 *   对应 rtl/w3c/evt_buf.v 的 DEPTH=1024 / LOW_WM=256 / HIGH_WM=768）。
 * ⚠️ 这三个数【不是我方猜的】—— 是 FPGA 侧给的。改它们前先问 FPGA 侧。 */
#define BLE_FPGA_EVT_BUF_DEPTH    1024u
#define BLE_FPGA_EVT_BUF_LOW_WM   256u
#define BLE_FPGA_EVT_BUF_HIGH_WM  768u    /* 安全提前量上限（事件数） */

/* 默认 tick_inc（120 BPM @ PPQN=960, 50 MHz）= round(2^32*2*960/50e6) */
#define BLE_POOL_DEFAULT_TICK_INC  164927u

/*
 * ⭐⭐⭐ 放水限流（🔴 2026-09-23 重做 —— 原来是"限帧数"，那是错的）
 * ---------------------------------------------------------------------------
 * 🔴 旧做法的两个问题：
 *   ① `BLE_POOL_MAX_FRAMES_PER_PUMP = 64`（帧）配 2 ms 周期
 *      ⇒ 理论 32,000 帧/s，⚠️ 而 FPGA 只消费 ~69.5 事件/s ⇒ **快 460 倍**
 *   ② 🔴 **`vTaskDelay(2ms)` 只是"至少 2 ms"** —— 被调度器延迟后，
 *      `elapsed` 与 `due_tick` 会【累积变大】⇒ 下一轮一次发更多 ⇒ ⚠️ 突发
 *
 * ⭐ 新做法：**按【tick】限流，⛔ 不按帧数** ——
 *    单轮最多把 `due_tick` 推进 `BLE_POOL_MAX_TICK_ADVANCE` 个 tick。
 *
 * ⭐ 取值依据（⚠️ 2026-09-30 【重算】—— 原依据用错了周期，🔴 见下方更正）：
 *
 * 🔴🔴 **更正记录：原注释按 `pump 周期 2 ms` 算，⚠️ 而【实际周期是 ~14 ms】**
 * ---------------------------------------------------------------------------
 * ⭐ 实测（2026-09-30）：
 *   · `task_pool_pump` 用 `BLE_DELAY_TICKS_AT_LEAST_1(2)`
 *   · `CONFIG_FREERTOS_HZ = 100` ⇒ `pdMS_TO_TICKS(2) = 0` ⇒ 被抬到 **1 tick = 10 ms**
 *   · ⚠️ 再叠加任务执行时间与调度抖动 ⇒ ⭐ **实测轮周期 P ≈ 14 ms**
 *     （⭐ 反推：P = 31 tick ÷ 2217 tick/s ≈ 13.98 ms）
 *
 * 🔴 **⇒ 原注释"正常一轮推进 3.8 tick、取 8 倍余量 31"是【基于错误周期】的**：
 *     按真实 P≈14 ms，一轮【本应】推进 `1920 × 0.014 = 26.9 tick`
 *     ⇒ **31 只剩 1.15 倍余量**（⛔ 不是 8 倍）。
 *
 * ⭐⭐ **更关键的量纲问题**：限流上限对应的速率必须 **≥ 音乐速率**，
 *     否则 🔴 **固件会被上限【顶住】跑不快 ⇒ 必然偏慢**。
 *       · 上限速率 = `MAX_TICK_ADVANCE / P`
 *       · 要求 `≥ 1920 tick/s` ⇒ `MAX_TICK_ADVANCE ≥ 1920 × P`
 *     ⚠️ 而原值 31 配 P≈14 ms ⇒ 上限 **2217 tick/s** ⇒ 略高于音乐
 *     ⇒ ⚠️ **一旦因首轮欠账或任何抖动落后，它就会以上限速率"追赶"**
 *     ⇒ 🔴 **表现为放水偏快（pace < 1）** —— ⭐ 这正是实测到的现象。
 *
 * ⭐ 取值依据（⭐ 新）：
 *    · 音乐速率 = `BPM×PPQN/60 = 1920 tick/s`（@120 BPM / PPQN=960）
 *    · 轮周期按 **P ≈ 14 ms** 保守估计 ⇒ 一轮本应推进 **≈ 27 tick**
 *    · ⭐ 取 **26** ⇒ 上限速率 = `26 / 0.014 = 1857 tick/s`
 *      ⇒ ⭐ **略低于音乐速率** ⇒ ✅ 落后时**只能慢慢还**，⛔ 不会超速
 *      ⭐ 这符合 `pool.c` 的纪律「**宁可饿着（可见 underrun），不可撑着（静默溢出）**」
 *    · ⚠️ 取整为 26（⭐ 若将来把轮周期改成 10 ms，应改为 ≈ 19）
 *
 * 🔴 **⛔ 不要为了"追得上"而调大本值** ——
 *    ⚠️ 那会让上限速率高于音乐速率 ⇒ 🔴 **正是"撑着"的那一侧**。
 *    ⭐ 真的要更快，应该【提高 pump 频率】（⛔ 不是放宽限流）。
 *
 * ⚠️ 副作用（⭐ 这是【故意】的、且是安全的）：
 *    若 ESP32 被长时间卡住，`due_tick` 会落后。
 *    ⭐ 新逻辑【不追赶】—— 每轮只推进有限 tick，落后会慢慢积累（`late_ticks_max` 看得见）。
 *    ⭐ 这正是我们想要的：**宁可 FPGA underrun（可见），⛔ 不要缓冲溢出（静默丢）**。
 */
#define BLE_POOL_MAX_TICK_ADVANCE     26u

/*
 * ⚠️ 保留一个【帧数】硬上限 —— 防病态情况
 *    （⭐ 比如某一 tick 内有海量事件，tick 限流管不住帧数）
 *
 * ⚠️ 取值依据：**FPGA 缓冲 = 1024 事件** ⇒
 *    单轮最多发 **512**（一半）—— ⚠️ 保证即使连发两轮也不会灌满。
 *    ⭐ 正常曲谱一轮只有几帧，这个上限【平时根本碰不到】。
 */
#define BLE_POOL_MAX_FRAMES_PER_PUMP  512u

/* pump 周期（ms） */
#define BLE_POOL_PUMP_PERIOD_MS       2

/* ===========================================================================
 * 9b. 🔴 空转任务的【安全延时】—— ⛔ 不要直接用 pdMS_TO_TICKS(小值)
 * ===========================================================================
 * 🔴 上机实测缺陷（2026-09-24，COM29）：
 *    Task watchdog 5 s 触发，`- IDLE0 (CPU 0)`、`CPU 0: drain`，
 *    栈回溯 = task_drain @ ble_main.c:484 → vTaskDelay。
 *
 * ⭐ 根因：`pdMS_TO_TICKS()` 是【整数除法】，且本工程
 *    `CONFIG_FREERTOS_HZ = 100`（⇒ 1 tick = 10 ms）：
 *
 *      pdMS_TO_TICKS(1) = (1 * 100) / 1000 = 0    🔴
 *      pdMS_TO_TICKS(2) = (2 * 100) / 1000 = 0    🔴
 *      pdMS_TO_TICKS(9) = (9 * 100) / 1000 = 0    🔴
 *      pdMS_TO_TICKS(10)= (10* 100) / 1000 = 1    ✅
 *
 * ⇒ ⚠️ **任何 < 10 ms 的值在 100 Hz 下全部塌成 0** ⇒
 *    `vTaskDelay(0)` 几乎不延时，只触发一次任务切换 ⇒
 *    ⚠️ 若该任务是最高优先级就绪任务，会【立刻被调度回来】⇒
 *    🔴 **忙循环**（每秒上千次）⇒ **饿死同核 IDLE0** ⇒
 *    🔴 **IDLE 任务正是靠运行来喂看门狗** ⇒ **5 s 后 TWDT 必然触发**。
 *
 * ⭐ 本工程的受害点（两处，均为优先级 9）：
 *    · `ble_main.c` `task_drain()` —— 缓冲空时 `pdMS_TO_TICKS(1)` = 0
 *    · `pool.c`     `task_pool_pump()` —— `pdMS_TO_TICKS(2)` = 0
 *
 * ⭐ 对策：统一走本宏 —— **保证至少 1 tick**（⛔ 永不塌成 0）。
 *    ⚠️ 语义与原意一致（"想等就得让出 CPU"），
 *       只是把"小于 1 tick 的请求"抬到 1 tick（本工程 = 10 ms）。
 */
#define BLE_DELAY_TICKS_AT_LEAST_1(ms) \
    ((pdMS_TO_TICKS(ms) > 0) ? pdMS_TO_TICKS(ms) : 1)

/* ===========================================================================
 * 9c. ⭐⭐ 起播触发（2026-09-30 新增）
 * ===========================================================================
 * 🔴 **为什么需要它**：`pool_start()` 原来【零调用】⇒ `s_running` 恒 false
 *    ⇒ 🔴 **`GPIO17` 永远不发数据**（⚠️ 日志里 `sent=` 恒为 0）。
 *
 * ⚠️⚠️ **背景：起播归谁管 —— 这是一个【尚未裁定】的架构问题。**
 *    · FPGA 侧拍板过「方案③：**上板手动按键起播**，⛔ 你那边不用改固件」
 *      （`files/20-代码/FPGA侧答复-ESP32对接清单-20260923.md:24/58`）
 *      ⭐ 但那句话的隐含前提是 **ESP32 只当透传管道（= 模式 A）**。
 *    · ⚠️ 而本工程实现的是**模式 B**（ESP32 自己按谱子时间放水）
 *    · 🔴 **⇒ 两者互斥**：模式 B 下起播必须由 ESP32 决定，
 *       否则【时间基准对不齐】（⭐ `pool_start()` 把谱面 t=0 锚在
 *       **ESP32 的 `esp_timer`** 上，见 `pool.c:461-462`）。
 *
 * 🔴 **⇒ 完整分析见 `files/20-代码/矛盾裁定单-方案3与模式B-20260930.md`。**
 *    ⚠️ **本节的实现【不预设裁定结果】** —— 它只是让"能起播"这件事可测。
 *
 * ⭐ 三种触发方式（⚠️ 编译期三选一，见下方 `BLE_START_TRIGGER`）：
 *    · `SERIAL` —— ⭐ **默认**。从 UART1 **RX（`GPIO18`）** 收单个 ASCII 字符：
 *        `S` = start（起播）  `X` = stop（停）  `R` = reset（清池）
 *      ⚠️ 注意：这是**给 FPGA 的那条 UART 的【接收方向】**，
 *         ⭐ 所以"按键"可以用 PC 串口 / USB-TTL **从远端模拟**，
 *         ⚠️ 上板后 FPGA 也能发（⭐ 但 FPGA 当前不发这些字符）。
 *      ⭐ 选它的理由：**⛔ 不需要额外接线**，现在就能测。
 *    · `GPIO`   —— ⭐ 用**外接按键**（⭐ 引脚见下方 `BLE_BTN_GPIO`），按下即起播。
 *      🔴🔴 **2026-10-01 更正**：⚠️ 原文写「用板载 **BOOT 键（`GPIO0`）**」⇒ 【已作废】——
 *         ⭐ **2026-09-30 已把按键从 `GPIO0` 改到 `GPIO6`**（⭐ 理由见下方 §9b：`GPIO0` 是 strapping 脚）。
 *         ⭐ **现值 = `BLE_BTN_GPIO = 6`**（本文件 `:425`），⭐ 接线 = 一端 `GPIO6`、另一端 `GND`（低有效）。
 *    · `NONE`   —— 关掉（⚠️ 回到"零调用"状态，`sent=` 会一直是 0）。
 */
#define BLE_START_TRIG_SERIAL   0
#define BLE_START_TRIG_GPIO     1
#define BLE_START_TRIG_NONE     2

#ifndef BLE_START_TRIGGER
#define BLE_START_TRIGGER       BLE_START_TRIG_SERIAL   /* ⭐ 默认：串口字符触发 */
#endif

/* ⭐ 按键引脚（⭐ 低有效，按下接地；⭐ 2026-09-30 从 GPIO0 改到 GPIO6）
 * ---------------------------------------------------------------------------
 * 🔴 **为什么不用板载 BOOT 键（GPIO0）** —— ⚠️ 它是【strapping 脚】：
 *    · ⭐ 官方（esptool Boot Mode Selection）：
 *      「The ESP32-S3 will enter the serial bootloader when **GPIO0 is held
 *        low on reset**」
 *      ⇒ 🔴 **按着 BOOT 键上电/复位 ⇒ 进下载模式,程序不跑**
 *        ⚠️ 症状是"串口一片安静" ⇒ ⚠️ **极易被误判成固件坏了**
 *    · 🔴 GPIO0 有 **45 kΩ 内部上拉**（官方明确）⇒ ⚠️ 接外部按键
 *      **必须用强下拉**（如 10 kΩ 到 GND），⛔ 否则可能压不下去
 *    · ⚠️ 板载 USB 的 `DTR` 就接在 `GPIO0` 上 ⇒ ⚠️ 有程序开关 `COMx`
 *      时若拉 DTR，可能**误触发复位/进下载**
 *  ⇒ ⭐ **结论：GPIO0 可以开发期凑合，⛔ 不能当产品按键。**
 *
 * ⭐ **选 `GPIO6` 的理由（⭐ 逐条排除了所有冲突）**：
 *    | 排除项 | 说明 |
 *    |---|---|
 *    | strapping | ⛔ 不是（`0/45/46` 才是） |
 *    | SPI flash / PSRAM | ⛔ 不是（`26~37` 是，⭐ 本模组八线 PSRAM） |
 *    | 原生 USB | ⛔ 不是（`19/20` 才是） |
 *    | 板载 RGB LED | ⛔ 不是（⭐ 本工程明确警告避开 `38/48`） |
 *    | 本固件已占用 | ⛔ 不是（UART1=`17/18`、UART0=`43/44`、UART2=`4/5`） |
 *    ⭐ 且它与串口屏的 `GPIO4/5` **相邻** ⇒ ⚠️ 接线方便。
 *
 * ⚠️ 接线：⭐ **按键一端接 `GPIO6`，另一端接 `GND`**（⭐ 低有效）。
 *    ⭐ 内部上拉已启用（`gpio_config` 里 `pull_up_en`）⇒ ⚠️ **外接上拉可省**，
 *    但 ⚠️ 长线/干扰环境建议**外加 10 kΩ 上拉到 3.3 V**。
 *    ⚠️ 建议串 **100 nF 到 GND** 做硬件消抖（⭐ 软件消抖也已开启）。
 */
#define BLE_BTN_GPIO            6
/* ⚠️ 消抖与轮询周期（⚠️ 都 ≥ 10 ms 才不会被 `pdMS_TO_TICKS` 塌成 0） */
#define BLE_BTN_POLL_MS         10
#define BLE_BTN_DEBOUNCE_MS     30

/* ===========================================================================
 * 10. ⭐ 串口屏（与 SPP 版同一套，走 UART2）
 * ===========================================================================
 * 屏型号：⭐ TJC3224T120_011R_A01（T1 系列 2.0 寸，电阻触摸，320×240）
 *
 * ⚠️ 电平（🔵 2026-09-23 用户确认）：
 *      · **串口信号电平 = 3.3 V** ✅ ⇒ ⭐ **可与 ESP32 直连，⛔ 不需要电平转换**
 *      · ⚠️ 但**供电 VCC 仍是 4.65~6.5 V** ⇒ 🔴 **必须给 5 V**
 *      ⭐ 关键区分：**"信号 3.3 V" ≠ "供电 3.3 V"** ——
 *        信号线直连没问题，⛔ 但 VCC 接 3.3 V 屏根本不亮。
 *
 * ⚠️ 引脚注意：本版 UART1 已给 FPGA（GPIO17/18）⇒ 屏改用 UART2。
 *    🔴 这与 SPP 版【正好相反】（那边 UART1=屏、UART2=FPGA）——
 *       ⚠️ 因为 S3 的 UART 编号与可用引脚不同，⛔ 别照抄 SPP 版的引脚。
 */
#ifndef BLE_HMI_ENABLE
#define BLE_HMI_ENABLE       1          /* 0 = 不接屏 */
#endif

#define BLE_HMI_UART_PORT    UART_NUM_2
#define BLE_HMI_BAUD         115200
#define BLE_PIN_HMI_TX       4
#define BLE_PIN_HMI_RX       5

#define BLE_HMI_BOOT_DELAY_MS   300
#define BLE_HMI_WAIT_BOOT_ACK   1
#define BLE_HMI_BOOT_ACK_MS     2000
#define BLE_HMI_REFRESH_MS      200
#define BLE_HMI_CMD_MAX         96

/* ---------------------------------------------------------------------------
 * 12. ⭐⭐ 板载 WS2812 RGB 灯（⭐ 2026-09-30 夜新增，用户 Q4 裁定）
 * ---------------------------------------------------------------------------
 * ⭐ 用户原话：「蓝牙连好了可以让灯亮一下」＋「开发板上好像有现成的 ws2812」
 *
 * ⭐ 已核实的硬件事实：
 *   · 板子 = ESP32-S3-DevKitC-1
 *   · 板载 RGB = ⭐ WS2812（⭐ 可寻址，⛔ 不是普通三色 LED）
 *   · 数据脚 = ⭐ GPIO48
 *
 * 🔴🔴 必须知道的硬件坑（⚠️ 否则"代码全对但灯不亮"）：
 *   板上 R17 与 GPIO48 之间出厂是【断开】的 ⇒
 *   ⭐ 必须用跳线把 RGB 下方的焊点短接，灯才会亮。
 *   ⇒ ⚠️ 若上板"灯不亮但日志说 init OK"，先查这个跳线，⛔ 别改代码。
 *
 * ⚠️ 与 BLE_LED_ENABLE（普通 GPIO 驱动【外部】LED）的区别：
 *    · WS2812_ENABLE  ⇒ ⭐ 板载那颗（⭐ 无需接线，⚠️ 但要短接跳线）
 *    · BLE_LED_ENABLE ⇒ ⚠️ 外接 LED（⭐ 要接线）
 *   ⭐ 两者可同时开（⚠️ 但通常只用一个）。
 *
 * 🔴🔴 **2026-10-01：默认【关闭】—— 安全优先**（⭐ 用户："先把灯关了，安全第一"）
 *
 * ⚠️ 用户提出的关键点：⭐ **WS2812 有【锁存】**
 *    ⇒ ⭐ 它把**最后一次收到的 24 位值锁住**，⚠️ 直到收到**新的完整帧**才改变
 *    ⇒ 🔴 **即使固件停了 / GPIO 空闲 / 甚至 ESP32 重启，
 *         只要不复位灯珠供电，它就一直亮着**。
 *
 * ⭐⭐ **所以"把代码关掉"【不够】** —— 必须**再显式发一次全 0**去清锁存。
 *    ⇒ ⭐ 本工程的做法（⭐ 两层）：
 *      ① `WS2812_ENABLE = 0`  ⇒ ⛔ 不用它做任何指示（⭐ 不会点亮）
 *      ② `WS2812_CLEAR_ON_BOOT = 1` ⇒ ⭐ **开机发一次全 0**，
 *         把**上一次遗留下来的锁存值清掉** ⇒ ✅ **保证灭**
 *    ⚠️ 只做①不做② ⇒ 🔴 **灯可能还停在旧颜色上**（⭐ 因为锁存还在）。
 */
#define WS2812_ENABLE        0        /* ⭐ 0 = 不用板载灯（⭐ 安全默认，2026-10-01） */
#define WS2812_GPIO          48       /* ⭐ 板载 WS2812 数据脚（⭐ 已核实） */
/*
 * ⭐ 开机清一次锁存（⭐ 与 `WS2812_ENABLE` **独立** —— ⚠️ 这点很重要）：
 *    · `WS2812_ENABLE=0` + `CLEAR=1` ⇒ ⭐ **清掉旧颜色后不再点亮**（✅ 安全默认）
 *    · `WS2812_ENABLE=1`              ⇒ ⭐ 正常当指示灯用（⭐ 此时开不开清都行）
 * ⚠️ 若确认灯已经灭透了，⭐ 可以把这条也设 0（⚠️ 但**留着无害**）。
 */
#define WS2812_CLEAR_ON_BOOT 1        /* ⭐ 1 = 开机发全 0 清锁存 */

/* ---------------------------------------------------------------------------
 * 12b. ⚠️ 可选：外部普通 LED（⭐ 与上面二选一即可）
 * ---------------------------------------------------------------------------
 * ⭐ 行为：⛔ 未连接 ⇒ 灭 · ✅ 已连接 ⇒ 亮
 */
#define BLE_LED_ENABLE       0        /* ⚠️ 0 = 不接外部灯（⭐ 改用板载 WS2812） */
#define BLE_LED_GPIO         7        /* ⚠️ 空闲通用脚，⭐ 与按键 GPIO6 相邻 */
#define BLE_LED_ACTIVE_HIGH  1        /* ⭐ 1 = 高电平点亮；⚠️ 接法不同就改这里 */
#define BLE_LED_ON_MS        0        /* ⭐ 0 = 连接期间【常亮】；⚠️ >0 = 只亮这么多毫秒 */

#endif /* BLE_CONFIG_H */
