hokuu1102/Gowin2026-PolySynth/tb/drivers/tb_tlc5916_driver.sv

`timescale 1ns/1ps

module tb_tlc5916_driver;

    localparam integer CLK_PERIOD_NS = 20;

    reg       clk;
    reg       rst_n;
    reg       start;
    reg [7:0] led_data;
    reg       outputs_enable;

    wire tlc_clk;
    wire tlc_sdi;
    wire tlc_le;
    wire tlc_oe_n;
    wire busy;
    wire done;

    integer tlc_clk_count;
    integer le_pulse_count;
    integer error_count;
    reg [7:0] captured_data;

    // ── A1 / A2 · 接线（2026-09-17 加：K-01/K-03 之前**零覆盖**）──────────
    //   A1（`chk_min_pulse`）：`OE`/`LE` 上不得出现窄脉冲 —— 对 `tlc_oe_n` 挂一个，
    //      因为 TI 手册明确"**恰好 1 个 CLK 宽**的 OE 低脉冲(101)"会把器件打进 Special Mode。
    //   A2（`chk_le_shift`）：`LE` 在移位时钟活动期间必须为低。
    //   ⚠️ 例化必须放在被连信号声明之后（Icarus 的 "Unable to bind" 就是声明顺序问题）。
    reg  oe_before, oe_during_busy;
    integer oe_wait;
    integer done_wait;         // ⭐ `done` 等待的循环变量（有上限，防挂死）
    integer done_timeout;      // ⭐ 上限拍数
    integer rec_wait;          // ⭐ 等 Normal-Mode 恢复序列结束的循环变量（有上限）

    // ⭐⭐ K-66：Normal-Mode 恢复序列的**度量**（证明它符合手册的 "101" 形态）
    integer rec_oe_low_edges;      // `OE` 低窗口里跨过了几个 CLK 上升沿（须 = 1）
    integer rec_le_high_during_rec;// 恢复期间 `LE` 为高的拍数（须 = 0）
    integer rec_oe_low_ns;         // `OE` 低电平持续 ns（须 ≥ 500）
    integer rec_clk_periods;       // 恢复序列发了几个 CLK 周期（须 ≥ 5）
    integer rec_enter_count;       // 进入恢复序列的次数（须 = 1）
    reg     rec_oe_prev, rec_clk_prev, rec_seen;
    time    rec_oe_fall_t;
    integer bit_walk;          // ⭐ 逐位走查用的循环变量
    wire [31:0] a1_err, a2_err;
    chk_min_pulse #(.NAME("tlc_oe_n"), .ACTIVE_LOW(1), .MIN_CYCLES(4)) u_a1 (
        .clk(clk), .rst_n(rst_n), .sig(tlc_oe_n), .err_cnt(a1_err));
    chk_le_shift #(.NAME_LE("tlc_le"), .NAME_SCK("tlc_clk")) u_a2 (
        .clk(clk), .rst_n(rst_n), .le(tlc_le), .sck(tlc_clk), .err_cnt(a2_err));

    // ── A8 · X/Z 传播监视（T3 · `tb/checkers/chk_xprop.sv`）──────────────
    // ⭐ 每个 tb 都应挂上它：X 传播是"仿真看着对、上板全死"的最常见来源。
    //    err_cnt 不直接判失败，而是在 initial 末尾并进本 tb 的 error_count（结论仍由 tb 给）。
    // ⚠️ 例化必须放在**所有被连信号声明之后**（Icarus 报 "Unable to bind wire/reg/memory
    //    `captured_data`" 就是这个原因，不是信号名写错）。
    wire [31:0] a8_clk, a8_sdi, a8_le, a8_oe, a8_busy, a8_dat;
    chk_xprop #(.W(1), .NAME("tlc_clk"))  u_a8_clk  (.clk(clk), .rst_n(rst_n), .sig(tlc_clk),      .err_cnt(a8_clk));
    chk_xprop #(.W(1), .NAME("tlc_sdi"))  u_a8_sdi  (.clk(clk), .rst_n(rst_n), .sig(tlc_sdi),      .err_cnt(a8_sdi));
    chk_xprop #(.W(1), .NAME("tlc_le"))   u_a8_le   (.clk(clk), .rst_n(rst_n), .sig(tlc_le),       .err_cnt(a8_le));
    chk_xprop #(.W(1), .NAME("tlc_oe_n")) u_a8_oe   (.clk(clk), .rst_n(rst_n), .sig(tlc_oe_n),     .err_cnt(a8_oe));
    chk_xprop #(.W(1), .NAME("busy"))     u_a8_busy (.clk(clk), .rst_n(rst_n), .sig(busy),         .err_cnt(a8_busy));
    chk_xprop #(.W(8), .NAME("captured")) u_a8_dat  (.clk(clk), .rst_n(rst_n), .sig(captured_data),.err_cnt(a8_dat));

    tlc5916_driver dut (
        .clk            (clk),
        .rst_n          (rst_n),
        .start          (start),
        .led_data       (led_data),
        .outputs_enable (outputs_enable),
        .tlc_clk        (tlc_clk),
        .tlc_sdi        (tlc_sdi),
        .tlc_le         (tlc_le),
        .tlc_oe_n       (tlc_oe_n),
        .busy           (busy),
        .done           (done)
    );

    always #(CLK_PERIOD_NS / 2) begin
        clk = ~clk;
    end

    // TLC5916 samples SDI on each rising edge of its serial clock.
    // ⚠️⚠️ 必须**排除 Normal-Mode 恢复序列**（`K-66`）的时钟：
    //    那段序列会**故意**发 6 个 `tlc_clk` 周期（手册要求），它们**不是数据移位**。
    //    ⛔ 如果不排除，计数器会多算（实测 `clock count=10, expected 8`）⇒ 假失败。
    //    ⭐ 判据：只在 `recovering == 0`（主 FSM 接管后）才计数。
    //      ⚠️ 用**层次化引用** `dut.recovering`（iverilog 与 Gowin 都支持，见 `K-63` 的边界）。
    always @(posedge tlc_clk) begin
        if (rst_n && dut.recovering !== 1'b1) begin
            captured_data = {captured_data[6:0], tlc_sdi};
            tlc_clk_count = tlc_clk_count + 1;
        end
    end

    always @(posedge tlc_le) begin
        if (rst_n) begin
            le_pulse_count = le_pulse_count + 1;
        end
    end

    // ⭐⭐ K-66：恢复序列的度量（只在 `dut.recovering` 有效期间统计）
    always @(posedge clk) begin
        // 进入次数（上升沿计数）
        if (rst_n === 1'b1 && dut.recovering === 1'b1 && rec_seen === 1'b0) begin
            rec_seen = 1'b1;
            rec_enter_count = rec_enter_count + 1;
        end
        if (rst_n !== 1'b1 || dut.recovering !== 1'b1) rec_seen = 1'b0;

        if (rst_n === 1'b1 && dut.recovering === 1'b1) begin
            // ① `LE` 必须全程低
            if (tlc_le === 1'b1) rec_le_high_during_rec = rec_le_high_during_rec + 1;
            // ② CLK 上升沿计数（用于"低窗口跨过几个上升沿"）
            if (tlc_clk === 1'b1 && rec_clk_prev === 1'b0) rec_clk_periods = rec_clk_periods + 1;
            // ③ `OE` 低窗口跨过几个 CLK 上升沿 + 低电平宽度
            if (tlc_clk === 1'b1 && rec_clk_prev === 1'b0 && tlc_oe_n === 1'b0)
                rec_oe_low_edges = rec_oe_low_edges + 1;
            if (tlc_oe_n === 1'b0 && rec_oe_prev === 1'b1) rec_oe_fall_t = $time;
            if (tlc_oe_n === 1'b1 && rec_oe_prev === 1'b0)
                rec_oe_low_ns = ($time - rec_oe_fall_t) / 1;   // timescale 1ns ⇒ 直接是 ns
            rec_oe_prev = tlc_oe_n;
            rec_clk_prev = tlc_clk;
        end
    end

    task automatic send_and_check(input [7:0] expected_data);
        integer errors_before;

        begin
            errors_before = error_count;
            tlc_clk_count  = 0;
            le_pulse_count = 0;
            captured_data  = 8'h00;

            // ⭐ 等 Normal-Mode 恢复序列跑完（`K-66`）：复位/上电后它会占若干 `tlc_clk` 周期。
            //    ⚠️ 不等的话：① 恢复序列的时钟会被误算进"移位位数"；
            //              ② 恢复期间 `OE` 是关断的 ⇒ 会误判"tlc_oe_n should be low"。
            //    ⭐ 这段等待**有上限**（防挂死）。
            for (rec_wait = 0; rec_wait < 400; rec_wait = rec_wait + 1) begin
                @(negedge clk);
                if (dut.recovering !== 1'b1) rec_wait = 400;
            end

            @(negedge clk);
            led_data = expected_data;
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
