hokuu1102/Gowin2026-PolySynth/(commit log)

2026-09-13 docs: 初始化项目文档集（FPGA 实时多音色合成电子乐器引擎）
    赛题：2026 嵌入式芯片与系统设计竞赛 · FPGA 创新设计赛道 · 选题二
    入库内容：
    - 唯一文档索引 文档地图.md + 总纲 交接文档 v2.0
    - 方案抉择/：当前方案总览、产品形态决议清单、硬件选型表（56 项器件）、
    方案选择档案（中立版）、左手区方案（M1 定稿）+ 两张结构说明图
    - 模块/：模块决策表 + M1~M10 逐模块决策表、硬件接口总表（J1~J10）、
    整体模块框图、音频/LED/电源/FPGA 平台各模块方案
    - 执行类：机械与硬件待做任务表、采购与验证清单、待与队友讨论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
    [Keyboard Swidget.stl, obj_1_Object_1.stl]
2026-09-13 docs(git): 建立 Git 约定与文档引用检查（合并 4 次零碎提交）
    把 bcac22c / e6782f7 / 84d184a / 82ea34f 四次零碎提交合并成一次
    （内容等价 —— reset --soft 不碰工作区，最终提交就是当时工作区的快照；
    丢的只是次序）。次序里每一条「原说法 → 更正 → 原因」全部保留在下面。
    ═══════════ 一、建立了什么 ═══════════
    · CONTRIBUTING.md（新）—— Git 约定：分支策略 / 提交信息格式（6 种类型）/
    决策变更的文档约定 / 文件命名 / 不提交的东西 / 推送前 30 秒自查 /
    CI 说明 / 常用命令 / 推荐 Tag 节点 / 一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
    [键帽1.0.SLDPRT, 键帽1.0.STEP]
2026-09-13 docs(计划): 新增项目总览时间线（6 大块 / 三人分工 / 3 个硬节点）
    起算 9/13、截止 11/4 —— 53 天跨度，扣掉中秋(3天)+国庆(7天)共 10 天
    法定假，实际可用 43 天；再扣视频 2 天 ≈ 41 天。
    排期的支配因素是 2026 年这两个假期（据国务院办公厅通知）：
    中秋 9/25(五)–9/27(日)
    国庆 10/1(四)–10/7(三)
    打样厂在这 10 天停工，但【焊接调试是我们自己动手、不受工厂影响】，
    由此定出全项目最关键的一天：
    ⭐ 9/24 前必须投板。
    抢到 → 回板约 9/28–9/30，国庆 7 天变成「焊接联调周」；
    错过 → 回板拖到 10/8 之后，国庆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
2026-09-13 revise(计划): 考试周掀掉 10/28 冻结，改为 10/18；画板按板分摊
    原说法（本文件上一版）：
    · 三个不能挪的日期 = 9/16 下单 / 9/24 投板 / **10/28 冻结版本**
    · 可用时间 **43 天**（53 天跨度 − 10 天法定假）
    · 三人分工是「一人一条主线」的独占式分法
    · FPGA 平台仍算未决项（60K 或 138K）
    更正：
    · 第三个硬节点改为 **10/18（功能冻结）**。
    · 可用时间改为 **34 天**：43 − 9 天备考/考试 = 34；再扣视频 2 天 ≈ 32 天。
    · 开发窗口从「9/13–10/28」压缩到「9/13–10/18」，即 **26 天**；
    10/29–10/31 只有 3 天，且是隔了 9 天没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
2026-09-13 revise(计划): W3 改为三人按模块分担；国庆降为低人力周
    · 国庆 7 天按「联调周」排（前提"三人能留校"，当时列为待确认项）
    · W3（FPGA 音频引擎）由「乙」一人主责
    · 分工是「主责 + 搭手」矩阵，一人一条主责线
    · M1a 验收写明"上板或仿真均可"
    · 国庆 7 天改为**低人力周** —— 只排「一个人就能做完」的工序
    （焊接/通电/插轴、3D 打印、串口屏与 LED 单独调试、EDA 仿真与
    时序收敛、文档与视频脚本、随手录过程素材）；
    任何需要三人凑齐的事（整机联调、音色设计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
2026-09-13 docs(音频): 补「开发期出声验证」路径，分清验证与交付
    问题起于：手上这块 60K 板（不是 Tang Mega 60K）核心板自带 3.5mm 耳机口，
    不接外设能不能先把音色合成跑起来验证？
    结论：能，而且这是眼下最该做的第一步。但原文档只写了【最终交付】的音频
    链路（FPGA→I2S→DAC→Line Out→有源音箱），没有区分【开发期怎么听到声音】，
    容易被误读成"板上能响就等于音频方案已解决"。故新增 §〇。
    新增内容：
    ① 三种开发期出声方式，以及各自能/不能验证什么：
    · 仿真导出 WAV —— 能验音色/复音/ADSR/混音/算法；不能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
2026-09-13 docs(硬件): 基石板资料现状、开发期出声验证方法；更正 .cst 定位
    ═══════════ 一、基石板资料（新增 files/开发板与引脚资料.md）═══════════
    来源：Desktop\FPGA\资料\02-原理图\ 下的原理图 PDF（文字层可提取，
    网络名/位号/图框标题/页码都可读）。已确认的事实：
    · FPGA 芯片 = **GW5AT-LV60PG484A** —— 与赛题适配板（Tang Mega 60K）
    **同一颗芯片**。所以它的综合/布局布线资源报告**直接有效**：
    综合一版 32 复音引擎看 BSRAM 占用，即可判定 60K 够不够，
    **不必等 60K 申请结果**。（例外：.cst 不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
2026-09-13 chore(repo): 仓库迁到全 ASCII 路径；接入经验库并记录基石板资料
    本次合并了两件事（都是环境与知识基础设施层面的）：
    ═══════════ 一、仓库迁到全 ASCII 路径 ═══════════
    原位置：C:\Users\hokuu\Documents\学校存档\在泥电\比赛\FPGA2026 （中文）
    新位置：C:\Users\hokuu\Desktop\FPGA\FPGA2026 （全 ASCII）
    原因：**高云工具链按本地代码页解析路径**，遇非 ASCII 目录会报
    `ERROR SORT-1002 : cannot open Verilog file`（路径显示成 ????），
    同时 Hierarchy 视图一片空白、选不到顶层模块。
    这是上一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
2026-09-13 docs(规划): 评分规则对齐、架构决策 A2、延迟/资源预算、W3 接口冻结草案
    本轮把"规划层"的空缺系统地补了一遍。起因是回头逐条核对赛题原文，
    发现两个「文档里完全空白、但直接参与评分」的项。
    ═══════════ 一、⭐ 两个空白（最重的发现）═══════════
    新增 files/方案抉择/评分规则对齐.md —— 把《选题指南》选题二逐条
    （基础要求 3 / 拓展要求 4 / 核心评分规则 3）落到我们的方案上：
    ① ⛔ **「测试模式」完全没提，但它是现场验证的必需功能**
    原文：「支持测试模式下输出多路不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
2026-09-13 docs(音色+定案): 音色设计与采集链复核；定「最方便改的版本」；补齐 A3/A5/A6/A7
    起因：核对赛题原文后发现两处「文档完全空白但参与评分」的项，随后按团队
    复核结论把架构定案、并补齐了 A 类剩余四项。
    ═══════════ 一、⭐ 音色设计（新增 files/模块/音色设计.md）═══════════
    红线「音色数 ≥2」—— ⛔ 不是"能换表"，而是 ≥2 种听得出不同的乐器音色。
    而音色是 W3b 开工前唯一还缺的东西（不知道做什么音色，就不知道波表和
    ADSR 要什么参数）。
    三条设计原则：① **音色要匹配我们的输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
2026-09-13 docs(硬件): 结构清单只留待讨论项；D3 改用板载 DAC；更正 LED 颜色状态
    ═══════════ 一、结构清单重构（按用户要求）═══════════
    用户原话：「我确定的东西就不用再讨论了，只保留我说讨论的」
    ⇒ `files/硬件结构待讨论清单.md` 重构：
    · 新增 §三「✅ 已定（2026-09-13 拍板）—— ⛔ 不再讨论」共 14 项，
    只留作**约束边界**（后续设计不得违反）
    · §四「🔴 待讨论项」从原来的 5 组 15 项**缩减到 3 项**
    · §六 讨论顺序建议：原"六步依赖链"已基本失效（绝大部分已拍板），改为只列剩余项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
2026-09-13 docs(硬件+流程): 硬件方案收口 —— 板子划分、P4 右手板、LED 单色、尺寸链 20 mm
    本轮把硬件方案整块收口。下面每一节都保留了「原说法 → 更正 → 原因」；
    细粒度过程记录见本地存档分支 archive/2026-09-14-硬件方案收口（6 个 commit）。
    ═══ 1. 板子划分：新增 files/板子划分与板间接口.md ═══
    5 块实物 / 4 种设计：
    · P1 拓展板 ×1 —— FPGA 引脚引出 + 外设引脚的分配中枢
    · P2 电源板 ×1 —— DC 12 V 给 FPGA 板 + 5 V / 3.3 V 给外设
    · P3 左手区板 ×2 —— 两块完全相同，每块 8 轴位 + 1 片 MCP3208
    · P4 右手区板 ×1 —— 摇杆（拨弦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
2026-09-13 docs(组织+RTL): 文档按主题重组、清私人语气；RTL 开工就绪（代码总览图 + 阻塞项复核）
    本轮把「项目文档体系」立起来，同时给出写代码的人开工所需的一切。
    细粒度过程记录见本地存档分支 archive/2026-09-14-*（共 8 个 commit）。
    ═══ 1. 文档按主题重组（38 个文档从平铺改为 6 个目录）═══
    原布局：文档平铺在 files/ 下，外加两个语义不清的目录（方案抉择 / 模块）
    新布局：
    files/00-总览/ 文档地图 · 队友上手指南 · 项目时间线 · 规划待办 · 待与队友讨论 · 作品简介
    files/10-硬件/ 接口总表 · 板子划分 · 开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
2026-09-14 docs(硬件+电源+组织): 硬件方案全面收口 —— 采购缩到 7 项、TLC5916 定案、电源方案重写
    本轮把硬件从「选型讨论」推进到「可以照着下单和画板」的收口状态。
    细粒度过程记录见本地存档分支 archive/2026-09-14-采购与库存收口（17 个 commit）
    与 archive/2026-09-14-电源与备料收口（2 个 commit）。
    ═══ 1. ⭐ LED 驱动定案：TLC5916ID（8 路恒流，VDD = 3.3 V）═══
    选型沿革五轮（完整留档，防重复讨论）：
    74HCT595 → 否：整片总电流上限约 70mA，8 路 @12mA = 96mA 超标
    TLC5928 → 否：规格合适但封装全细间距（SSOP 0.635 / TSSOP 0.65 / VQFN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
2026-09-15 docs(硬件): 左手板评审收口 —— 五轮评审累计修 13 项；原理图 V1.0 与 PCB 均已画完
    【新增】files/10-硬件/左手板原理图评审.md
    - 五轮评审逐条留档，写法是"结论 + 依据"，依据可追溯到网表原文或数据手册原文
    - 累计修掉 13 项，其中 2 个致命：
    1) 8 路霍尔全并到同一个 ADC 通道（物理上无法分辨按了哪个键）
    2) TLC5916 的 OE 网络与 U4.13 断开（8 路输出永久关断，灯全不亮）
    【数据手册核对】TI SLVS695D（TLC5916/TLC5917）与 圣邦微 SGM2019
    - OE(ED2) 是低有效（低=输出使能，高=全部关断），且内部自带 500k 上拉 => 悬空即灭
    - Special Mode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
    [左手板.step, 左手板单板.step]
2026-09-15 docs(硬件): 左手板收口 —— 接口改为单方向单组座；记录排线走板背与垫板厚度方案
    【已核对】原理图 23:25 版 ↔ PCB 23:24 版逐脚一致
    - 用 .epro2 解析比对：72 个带网络的元件与原理图网表一一对得上
    - 6 处地已改对：U2.2 / C7.2 / C30.1 / C26.1 / C27.1 -> AGND
    - C31 与 C28 已删除（原理图与 PCB 同步，不再是原理图多、PCB 少）
    - R10 已挪到 ADC 旁：R10 与 U1 标注间距 7.7mm（顶层）/ 5.0mm（装配层），此前约 39mm
    => AGND/GND 的单点汇合点落到 ADC 脚下
    【接口变更】取消 _2 那一组座
    - LED_2 / SPI_2 / 模拟电源2 / 数字电源2 在原理图与 PCB 中均已删除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
2026-09-16 chore(LED): 加入 TLC5916 驱动与回归仿真
    加入单颗 TLC5916 正常模式串行驱动，遵循同步低有效复位约定并在复位时关闭 LED 输出。
    加入覆盖 00/A5/FF/3C/5A、时钟、锁存、OE 和同步复位的自检查 Testbench，以及可复现的 PowerShell 运行脚本和验证说明。硬件验证待上板，系统集成时两块左手板各实例化一次。
2026-09-16 docs(硬件+代码): 右手区双板方案定稿、板A原理图两轮评审、AI规划RTL的Prompt
    【新增】files/10-硬件/右手板方案.md —— 右手区"一页看完"
    - 拆成两块 10x10（均在免费打板额度内）、星形拓扑、互不互联、各自一条排线
    · 板 A = 必做最小输入版：摇杆(拨弦) + 2 推子 + 音量 + MCP3208 + LM393 + LDO
    只吃一路 5V_A；出 3 个座（SPI_1 8P / 触发 4P / 模拟电源 4P）
    · 板 B = 串口屏的替代品：0.96" OLED(SPI) + EC11 + 4 按键 + 4 双色灯(TLC5916) + 74HC165
    - 决策：板 B 的 PCB 一定要打、器件可后焊（省掉"发现屏不行再补板"的那轮打样）
    【定案】
    - 状态灯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
2026-09-16 docs(约定+硬件+代码): 板A原理图定稿入档；CONTRIBUTING 补 rebase 路线；Prompt 更正口径
    【板A 原理图定稿】files/10-硬件/右手板方案.md 新增 §十（四轮评审全部闭环）
    - 逐项核对通过的器件/取值表：模拟 RC 1k+10nF、迟滞 R5/R6=470k、
    阈值 3296W 完整分压(1->3V3/2->滑动端/3->AGND)、R15/R16 上拉(CS/MISO)、
    R10 0欧地桥、R12-R14 33欧串阻、音量 RK09L1140A5P(B10k 线性)、探针命名
    - 冻结三条传给 RTL 的硬约定：
    1) 比较器输入必须接 PICK 而非 CH0 —— 这是 UP/DOWN 延迟小于 5ms 可证明的硬件前提
    2) ADC 同通道重访 50us 即可，整片帧 0.5ms（每通道 2kHz）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
2026-09-16 fix(文档地图): normalize line endings after API upload
2026-09-16 docs(代码+硬件): 消掉 K-04/K-05 两份过时文档；原理图与网表入库
    【K-04】files/20-代码/W3接口冻结表.md
    - expr_param_t 改为 vibrato_depth + vibrato_rate + master_volume + timbre
    - 真正删除已作废的 pitch_fine[11:0]（此前只在正文声明取消、结构体里还留着）
    - 正文"速率固定 5~6 Hz"改为推子 2 控制 1~12 Hz，并注明需斜率限制/死区迟滞
    - 附 2026-09-16 更新说明表（原写法 -> 现在 -> 依据）
    【K-05】files/20-代码/代码总览图.md
    - 拓扑图与模块表："共用 SCLK/MOSI/MISO + CS1/2/3" 改为"每组各自四线，
    SCLK/MOSI 可扇出但 MISO 必须 3 个独立输入，每片各自 CS"
    - chan_sca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
2026-09-16 docs(代码): 交叉核对第三份架构文档，登记 K-28/K-29/K-30 三处口径冲突
    第三份文档 files/20-代码/合成引擎架构决策.md（475 行）审阅结论
    - K-28 阻塞级：波表 ROM 能否共享，两份架构文档直接矛盾
    · 合成引擎架构决策.md 2.1 認為可共享（表是音色数据，不是振荡器状态）
    · RTL代码结构与接口规划.md 0.1 采取保守路线（每 lane 一块 ROM bank，
    否则不敢按 N 个波表振荡器申报）
    => 决定振荡器数申报口径 / BSRAM 预算 / 平台选型，最高优先级待拍板
    - K-29 Test Mode 档位：4/8/16/32/64 vs 最新的 4/8/16/32 必做、64 只预留
    - K-30 FM 计数口径：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
2026-09-16 docs(代码): 问题合集补全 K-31~K-33 并修正 K-05 状态
    - K-05 由"已解决"改为"部分解决"：代码总览图已改，但采集链参数复核/延迟预算逐段分解还没改
    （旧口径是 24 通道共享一条 SPI 总线 / 每通道 2kHz）
    - K-31 采集链参数复核.md 与 延迟预算逐段分解.md 仍按共享总线估算，
    需按 3 组独立四线 + 1k/10nF 模拟 RC + 整片帧 0.5ms 重算端到端延迟预算
    - K-32 多片 TLC5916 的时钟/锁存分组：各片 SDI 独立，LED_CLK/LE/OE 可共用，
    但灯的移位 CLK 与 ADC 的 SPI SCK 不是同一条；RTL 顶层端口分组待冻结
    - K-33 板 B 原理图尚未画，K-14/K-15/K-26 全部挂在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
2026-09-16 docs(代码): 新增开工指南（按底层先后顺序 L0~L12）
    - 13 层自底向上：L0 环境与仿真脚手架 -> L1 时基 clk_gen -> L2 i2s_tx ->
    L3 单振荡器 DDS -> L4 ADSR -> L5 参数与音高接口 -> L6 复音与复用 ->
    L7 控制量(音量对数映射/颤音LFO/变调) -> L8 采集链 -> L9 人机底层 ->
    L10 映射与演奏语义 -> L11 顶层集成 -> L12 CST/上板
    - 每层给出：做什么 / 依赖哪一层 / 验收标准 / 卡谁（引用 K 编号）
    - 明确"先做保守版"的后门：L6 波表先按每 lane 独立 ROM bank（K-28 未定）
    - 今天三件事：L0 脚手架、L1+L2 直通 M1 出声、L9 给 TLC5916 加 OE guard
    - 分工按层切三条线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
2026-09-17 docs(总览): 新增本周计划（0916 周三 至 0920 周日）
    - 总目标：RTL 走到 M1 第一次能出声，并让 M2 低延迟在仿真里可证明；
    硬件把板A PCB 与板B 原理图推进到能投板
    - 必达：M0+M1、板A PCB 画完、TLC5916 加 OE guard（K-01）
    - 争取：M2（用合成 UP/DOWN 激励，不依赖实物）、M3 骨架
    - 不做：效果器/FM/UI 实装/CST 冻结（卡 K-22/K-23）
    - 逐日：周三 L0 脚手架+OE guard+板A PCB；周四 M0 打通；周五 M1 出声 + 板A 送打样；
    周六 复音保守版+低延迟路径+板B 原理图；周日 周末验收+M2 论证+交叉复核
    - 三条 RTL 线按层切（甲通道线/乙合成核心/丙采集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
2026-09-17 docs(代码+总览): 新增仿真与验证方案与路线图；验收口径切到"仿真优先"
    前提变更：系统板(Tang Mega Dock)未到，只有旧基石板可做冒烟测试，
    "耳机口出声"这条验收路径不可用 => 所有里程碑改为以仿真证据判定。
    【新增】files/20-代码/仿真与验证方案.md
    - 三条铁律：一切验收要有可复现仿真证据 / 基石板不等于正式板(器件不同不能验时序) /
    没 tb 的模块视为没做完
    - 5 个必须共用的行为模型 S1~S5：MCP3208 从机(CS 高时 DOUT 高阻)、
    I2S 解串+DAC 重构(替代耳机听声)、TLC5916 从机(含 Special Mode 检测)、
    触点抖动、golden 音频参考
    -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
2026-09-17 docs(整理): 归档 10 份冗余/过时文档；新建"第一周"任务文件夹；建 sim/tb_all.ps1
    【归档到 files/历史/】（每份后缀写明原因，并新建 历史/README.md 说明归档规则）
    - AI规划代码结构-Prompt（产物已是架构文档）
    - 采集链参数复核 / 延迟预算逐段分解（旧"共享总线"与旧 RC 口径，K-31）
    - 整体模块框图（与代码总览图重复）
    - 验收计划（并入仿真与验证方案）→ 仿真与验证方案.md
    - 开工指南 / 第一周计划 / 路线图 / 开工任务分配（并入第一周任务）
    - 硬件结构待讨论清单（与待与队友讨论重复）
    - 同步修正全库对这些文件的引用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
2026-09-17 docs(代码): 队友架构文档里作废的旧延迟预算引用改为"已作废"提示（方案 2）
    - files/20-代码/RTL代码结构与接口规划.md 第 494 行原引用 files/20-代码/延迟预算逐段分解.md
    该文件已归档，且其两个前提（3 片 ADC 共享 SPI 总线、模拟 RC 10k+100nF/每通道 5ms）均已推翻
    - 改为删除链接并注明已作废、指向 K-07/K-31，避免后人继续引用旧数字
    - 文档引用检查恢复 0 硬错误
2026-09-17 docs(代码): 作废引用改为不含路径的字面写法，文档检查归零
    - 上一版仍写成 files/20-代码/延迟预算逐段分解.md 仍会被引用检查判为硬错误
    - 改为"原「延迟预算逐段分解」"，并指向 K-07/K-31
2026-09-17 docs(约定): CONTRIBUTING 新增"队友视角：远端已被推进怎么办"
    - 三条命令：fetch -> stash -> rebase -> stash pop -> 普通 push
    - 更好的办法：没写完就开 wip/<主题> 分支推，完全不碰 main（引用 PR #1 的既有习惯）
    - rebase 报 deleted by us 的两种处理（搬到历史新位置 / 按 K 条目放弃）
    - 自查代码注释里的文档旧路径：git diff | Select-String
    - 附 2026-09-17 文档整理的旧到新路径对照表（10 条）+ 整理后应优先引用的现行文档
2026-09-17 docs(约定): 路径对照表的旧路径列改为裸文件名，引用检查归零
    - 上一版对照表左列写成 files/20-代码/xxx.md 形式，被引用检查判为 10 处断链
    - 改为只写文件名并加说明（原都在 files/20-代码、files/00-总览、files/10-硬件 下）
2026-09-17 docs(总览): 第一周新增分工.md（四条线 + 你负责的硬件与协调部分 + 新会话启动 Prompt）
    - 四条线：甲通道线/乙合成核心/丙采集与人机/丁硬件与协调（你）
    - 你的部分：A1-A5 只有你能做的对外问询（K-28 波表ROM共享、K-22/K-23 Dock资料、
    K-24 DAC型号、K-25 串口屏电平、K-20 复位ball）；B 硬件线 T24-T26；
    C 纪律与看板（K清单/进度/推送前检查/不用 force）；D 可选技术活（推荐 tools 四脚本）
    - 新会话启动 Prompt：列出必须先读的 7 份文件 + 5 条硬约束 + 第一件事做 S2
    - 迁移检查清单：结论已入库、已推送、队友会用 wip 分支、首句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
2026-09-17 docs(总览): 分工.md 里的 wip/ 写法改为"wip/ 前缀分支"，引用检查归零
2026-09-17 docs(总览): 第一周分工与迁移方案定稿；文档引用检查归零
2026-09-17 feat(第一周地基): 文档口径裁决 + 回归与工具链地基（T1/T3/T4）+ 任务清单只留第一周
    本次交付 = 第一周前半段：先把"能被验证"这件事立起来，并消掉文档里会让人写错代码的口径冲突。
    ① 引用检查与文档一致性（fix）
    原现象：全仓 230 处引用写成裸文件名/缺目录，点击跳转会按"当前文档所在目录"解析 ⇒ 打不开。
    更正：按 tools/check_doc_refs.py 的三基准判定，补成【仓库根相对】95 处 / 28 个文件；
    ⛔ 故意写裸名的三处不动（CONTRIBUTING 的路径对照表、文档地图的索引表、队友的两份文档）。
    附带：.gitignore 里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
    [selftest_sine_1k.csv, selftest_sine_1k_spectrum.csv]
2026-09-17 feat(第一周·板卡与出声): 板卡/DAC 事实收口 + 时基与 I2S 落地（M0 时基 + M1 判据通过）
    ① 板卡四项未知一次解开（decide）——依据官方 60K 引脚约束 + Dock 原理图 + 两份官方例程
    · K-20 复位 = **AA13**（LVCMOS15 / PULL_UP）；⚠️ 原候选 Y12 其实是 Key_in[1] 按键
    · K-22 Dock 型号 = **Tang Mega 60K**（GW5AT-LV60PG484AC1/I0 + 底板 TANG MEGA NEO）；
    ⭐ **60K 与 138K 共用同一套底板 ⇒ 外设完全相同**（Sipeed wiki）
    · K-23 系统时钟 = **V22 / LVCMOS33**（⛔ 不是旧基石板 F13）
    · K-24 板载 DAC = **PT8211-S**（16 bit 立体声；功放 NS4263）；**不需要物理 MCLK**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
    [i2s_tx_l.csv, i2s_tx_l_spectrum.csv, i2s_tx_r.csv]
2026-09-17 feat(第一周·M0达成/工具链跑通): 顶层安全态 + M2 延迟实测 + Gowin 全流程（P1）
    - M0 达成：top.v（clk_gen + i2s_tx + 安全态 + 心跳 LED 活体见证）+ constr/top.cst（引脚全取官方 60K 约束）
    tb/top/tb_top_m0.sv 7/7：HP_BCK 16clk / HP_WS 1024clk 精确、PA_EN_n 全程为1且翻转0次、延时开功放只翻转1次、静音全0、A8 干净
    - T16/M2 达成（阶段结论）：tb/latency/tb_latency_m2.sv 50 次，max 1263clk=1.233帧（<2）、极差 0.0188ms（<0.1）
    延迟分解：输出级固有占 322~1260clk ⇒ 留给合成链 785clk=15.7us（K-44）
    - P1 跑通：Gowin2026.gprj + build_cli.tcl + constr/top.sdc + sim/gowin_build.ps1
    综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
    [latency_m2_stats.csv, top_m0_pa_trace.csv]
2026-09-17 T3 完成：A1~A8 八个检查器全部就册 + 每个都有一正一反负向自检
    - 新增 chk_min_pulse(A1 窄脉冲，含可选亚周期毛刺检查) / chk_le_shift(A2 LE 移位期低)
    chk_at_most_one(A4 片选互斥 + A5 MISO 单驱动源，同一结构判据共用) / chk_phase_advance(A7 相位只按 inc 前进)
    - A7 用不变量写法（增量必须= phase_inc，新旧 inc 都接受），jump_ok 给合法起音留出口，采样打一拍避免竞争
    - tb/checkers/tb_checkers.sv 扩展为 8 个检查器的正反用例：PASS + exit 0（日志里 13 行 ERROR [Ax] 是负向测试的预期输出）
    - 回归 6/6；文档：仿真与验证方案 §二 A1~A8 全部标已实装、任务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
    [chk_at_most_one.sv, chk_le_shift.sv, chk_min_pulse.sv, chk_phase_advance.sv, tb_checkers.sv]
2026-09-17 K-46：高云 .gprj 文件 type 写错会静默跳过（.sv 也是 file.verilog）+ 澄清「被解析 ≠ 被综合」
    实测：type=file.systemverilog 时日志无 Analyzing/Compiling、构建仍 exit 0 ⇒ 文件根本没被读。正确写法依据官方例程 cpu.gprj（.v 与 .sv 都写 file.verilog）。附带发现：未被顶层例化的模块只 Analyzing 不 Compiling ⇒ 不能当「能综合」的证据。工程已登记 tlc5916_driver.sv（丙的驱动）做语法检查；证据已刷新（Fmax 332.9MHz / 引脚 7/7 不变）。
2026-09-17 新增 bringup/ 验证专用文件夹：现有代码逐文件「能验什么」清单 + 基石板上板阶梯 + 一键验收矩阵
    为什么单独开文件夹：验证相关的东西（上板顶层/基石板工程/PC 脚本/清单）不混进 rtl/ 成品代码（用户 2026-09-17 要求）。目录名用 ASCII 是因为将来要把 Gowin 上板工程放进去（经验库 U44：高云遇中文路径报 SORT-1002）。
    bringup/01 逐文件清单：每个文件=保证什么/已验(带证据路径)/还能验(🟡不用板)/上板可验(🔵)/验不了(⛔)，含 18 行验收矩阵与「现在就能补、最值钱的 6 条」；bringup/02 基石板方案：仪器与引脚(按 ADDA 实机验证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
2026-09-17 审查与修复：把现有全部模块验证到位（R-01~R-21 / K-47~K-67）
    == 来源 ==
    独立对抗式审查（20 条发现）+ 开源同类实现调研 + 三颗芯片手册原件 + 实际 PCB 网表。
    验证方法论：判据本身也要被验证（变异测试 17/17）。
    == 两个最严重的（都是「仿真全绿却上板必错」那一类）==
    · R-03：i2s_tx 的 HP_DIN/HP_WS 与 HP_BCK 同沿变化，而 PT8211 手册原文
    「shifted to the input register in the rising edge of the BCK」⇒ 建立时间约 0。
    原有判据结构性看不见（解串模型「沿后打一拍取数」对数据变化沿不敏感）。
    修法：HP_BCK 复位值 0 改 1 ⇒ 数据在下降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
    [listen_1s.csv, top_m0_pa_trace.csv]
2026-09-17 芯片手册原件核对：TLC5916 / MCP3208 / PT8211 / NS4263（K-57~K-59、K-63）
    == 为什么 ==
    所有涉及外部芯片的结论都必须「查手册原文」，不能靠「标准做法应该是……」
    或第三方镜像。本批把四颗芯片逐条核对，并记录原件缺口与手册矛盾。
    == 核对结果 ==
    · TLC5916（TI 原件，完整可检索）
    - OE/LE 模式切换机制逐字确认：「one-clock-wide pulse on OE(ED2)」进入 Mode Switching，
    第 4 个 CLK 上升沿采 LE 决定去留 ⇒ K-01/K-03 修法依据加强。
    - 新增时序限值核对：tw(CLK)/tw(L)/tsu(D,ED1)/th(D) 全部满足，裕量 25~250 倍。
    - 发现 tw(OE) 大于等于 500ns 而我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
2026-09-17 硬件核对：实际 PCB 网表 + 拓展板连接方案 + 上拉/亚稳态口径（K-60、K-64、K-65）
    == 核对来源 ==
    从 lefthand_board.tel / righthand_board_A.tel 逐条核对「文档 ↔ 实际网表」，以网表为准。
    == K-65：文档与实际 PCB 有 3 处不一致（已更正）==
    · 左手板 SPI_1 实际是 8 针 XH2.54（CS/GND/MOSI/GND/MISO/GND/MCP_CLK/GND），
    不是文档写的 7 针含 3V3（供电走独立的 4P 座）。
    · 信号名是 MCP_CLK（经 33 欧姆源端串阻），不是 SPI_SCLK。
    · LED 座 LED_1 也是 8 针（LE/GND/LED_CLK/GND/SDI/GND/OE/GND）。
    两个 8P 座外形相同、针位定义不同 ⇒ 插错会不工作，靠丝印加线上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
2026-09-17 给队友的交接说明：这批改了别人什么（丙的 TLC5916 驱动 +244 行但接口未变、共用地基三处、乙/丙的新结论）+ force push 后拉代码方式
    起因：这批我改了丙负责的 tlc5916_driver.sv、动了三人共用的 tb/checkers、tb/models/i2s_rx_model.sv、sim/tb_all.ps1，并合并重写了远端历史（force push）。为避免队友拉到「我没写过的改动」而困惑，写一份按人分的交接说明：① 丙（TLC5916）：接口一个没变（端口无增删改名、仅新增有默认值的 OE_STABLE 参数），但有 3 处行为变化——OE 不再每拍跟随（等 IDLE+稳定窗）、LE 抬高推后 1 拍、新增上电 Normal-Mod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
2026-09-17 查实 V22 = 50 MHz（三处官方原件一致 + 反证），并记录「要不要换高速时钟」的量化结论（K-68）
    == 起因 ==
    Dock 原理图 /SYS_CLOCK/ 页有 100MHz / 210MHz / 125MHz 标签，而仓库里
    「sys_clk = 50 MHz」原来只是断言、没标出处 ⇒ 怀疑「实际是 100 MHz 而我们按 50 约束」。
    若真如此，fs / BCLK / LRCLK 会全部差 2 倍，且时序分析会乐观一倍 ⇒ 必须查实。
    == 查实结论：V22 = 50 MHz（三处独立证据一致）==
    1. 官方 TMDS_60HZ.sdc 第 1 行：create_clock -name clk -period 20 -waveform {0 10}
    => period 20 ns = 50 MHz
    2. 官方 NEO_DOCK.cst：IO_LOC "clk" V22 （与我们的 constr/top.cst 逐字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
2026-09-18 B6+B10：修 PA_ON_AFTER_RESET 交付默认值隐患（K-69）+ 给乙的验收判据包（K-70）
    == B6 · K-69：交付默认值会「让板子没声音」 ==
    问题：top.v 的 PA_ON_AFTER_RESET 默认值是 0 ⇒ 板载 NS4263 功放永远关断
    ⇒ 喇叭/耳机都没声音。而 I2S 波形、DAC 输入、所有仿真结论全都是对的
    ⇒ 这种「没声音」极难定位（会让人去查 RTL 白费几小时）。
    根因：把「测试配置」（M0 安全态）当成了「交付默认值」。
    修法：
    1. 默认值 0 → 1（复位后延时开功放，全程恰好 1 个下降沿 ⇒ NS4263 进 AB 类桥式）
    「0」保留为 M0 安全态验证档，由 tb_top_m0 显式传 0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
    [tb_top_m0.sv, tb_voice_accept.sv]
2026-09-18 chore(采集): 加入 MCP3208 驱动与扫描回归 (#2)
    实现单片 MCP3208 的 SPI 转换与 8 通道定时扫描，加入自检查 testbench、专项回归、Gowin 工程登记和验证说明。三片 adc_farm、顶层接入与实物验证保留为后续任务。
2026-09-19 基石板上板验证 + 合规口径收口（主办方答复已入档）
    ## 一、基石板上板验证（新增 bringup/jishi/，独立工程，⛔ 不改正式代码）
    - 独立 Gowin 工程 jishi/：一条命令跑通 综合→布局布线→bitstream（相对路径引用 rtl/，逻辑零改动）
    - 详细验证指南 bringup/04：信号表 / 选脚两条件 / 构建 / 阶梯 0~3 / 示波器接线与设置 /
    测量顺序 / 失败诊断表 / 本阶梯验不到什么 / 实测记录
    - 实测（GDS-2202E）：BCK 3.125 MHz、WS 48.8293 kHz（+24 ppm）、DIN 结构符合推算
    - K-72~K-77：脚本位置依赖、引脚未引出、不需 SMA、判据按最小重复单元、
    示波器触发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
2026-09-19 feat(w1-2): land deterministic Gowin wavetable pROM
    Add the reproducible 512x16 sine generator and HEX/CSV/MI assets, the wavetable_bank RTL interface, a generated Gowin pROM, behavioral and vendor-wrapper verification, and a synthesis-only top that proves one pROM/BSRAM with initialization data survives synthesis. Harden the regression runner against stale simulation images and keep machine-specific IP helper files out of version control.
    [sine_512x16.csv]
2026-09-19 feat(w1-2): add pROM DDS-to-I2S board proof
    Add a phase-continuous DDS core, dedicated 440 Hz Dock bring-up top, independent Gowin project, and external-interface tests. Record passing simulation, synthesis, timing, pin, pROM, and bitstream evidence.
2026-09-20 chore(采集): 补丙线 T13 calib + T14 debounce（含单元 tb、抖动模型、变异体 M19/M20）
    补上丙线（采集与人机）在仓库里缺失的两块，接口对齐现有 mcp3208_scanner 口径：
    T14 debounce（rtl/drivers/debounce.sv + tb/drivers/tb_debounce.sv + tb/models/bounce_src.sv）：
    - 4 按键 + EC11 A/B/SW 计数去抖，接 sync_input 前置（K-62 口径）
    - EC11 正交解码：正转/反转/非法跳变三态全测，13/13 通过
    - S4 触点抖动模型（bounce_src.sv）供单元 tb 复用
    T13 calib（rtl/drivers/calib.sv + tb/drivers/tb_calib.sv）：
    - 逐通道零点(tare)/满量程(span)标定 + 移位-减法除法器 + Q8.8 增益
    - 比例式（K-16）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
2026-09-20 docs(w1-2): mark board validation deferred
    Record that simulation and Gowin build have passed, while programming, listening, and oscilloscope checks remain not run until the Tang Mega 60K Dock arrives.
2026-09-20 chore(采集): 落地 L8 三片并行采集 adc_farm + S1 从机模型 + A4p 口径裁决
    补上丙线 L8 采集链的核心缺口：三片 MCP3208 的并行总控（K-79 裁决后落地）。
    adc_farm（rtl/drivers/adc_farm.sv，T11/T12 顶层）：
    - 三片并行采集：片 0 mcp3208_scanner 当主控，CS/SCLK/MOSI 同源扇出（K-79 实测锁步）
    - 三路 MISO 独立，各自经 sync_input 2 级同步（K-62），影子反串行器锁步取 12 位
    - 一次 sample_valid 原子提交 3×8=24 通道样本；帧周期 0.5ms（25_000 周期）
    - 串行 24 笔=1698Hz 不达标 → 并行 8 笔=5094Hz 达标（K-79 帧预算）
    S1 从机模型（tb/models/mcp3208_model.sv，T2 丙部分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
2026-09-20 feat(w1): complete synth voice and pitch acceptance
    Add independent ADSR state, integrate the real DDS+pROM+ADSR+I2S voice path, and formally verify held-note phase-continuous pitch updates.
    Simulation regression passes 21/21 and Gowin synthesis passes. Board listening and oscilloscope validation remain explicitly deferred until hardware arrives.
    [pitch_after.csv, pitch_after_peaks.csv, pitch_after_spectrum.csv, pitch_before.csv, pitch_before_peaks.csv, pitch_before_spectrum.csv, voice_i2s_chain_l.csv, voice_i2s_chain_peaks.csv]
2026-09-20 decide(第二周·自动功能与接口修正): 鼓机/节拍器/Looper 设计 + adc_farm 参数化 + timbre 语义修正
    ═══════════════════════════════════════════════════════════════════
    ⭐ 队友请先看这三条（接口/口径变了，别按旧接口写）
    ═══════════════════════════════════════════════════════════════════
    ① rtl/drivers/adc_farm.sv —— N_ADC 由"写死 3"改为参数化（支持 5/6 片）
    ·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
    [pitch_after.csv, pitch_before.csv, voice_i2s_chain_l.csv]
2026-09-20 fix(验证): K-87 —— 变异测试把"跳过"当"通过"，adc_farm 曾静默失去全部保护
    问题（我自己 2026-09-20 引入的回归）
    · 为支持可变片数，把 rtl/drivers/adc_farm.sv 的写死扇出改成 generate for
    ⇒ M21/M22 的锚点字符串（assign adc_cs_n[1] / miso1_shift）永久失配
    · 但脚本只统计"没抓到"（Caught -eq $false），而 skipped 的 Caught 是 $null
    ⇒ 不计入任何失败 ⇒ 仍然打印 PASS
    真正的危害
    · adc_farm（刚落地又被改过）在【无任何变异体守着】的情况下
    被测出"变异测试全绿" ⇒ "全绿"这个结论本身失去意义
    · 最危险的是本地一切自洽：回归 25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
2026-09-20 审查: 队友代码与 TB 五步审查完成 + K-89
    第 5 步汇总（详见 meeting-20260918/07-队友代码审查计划.md）
    一句话结论
    · 队友代码与 TB 质量是好的：核心链路真链路端到端验过、golden 多数有独立来源、
    全部 tb 有超时保护、变异体覆盖到位
    · 发现的问题多数是"结构性/边界"问题，不是"假绿"或功能错误
    · 最严重的一个是我自己引入的（K-87 + K-89）
    新增 K-89：adc_farm 的兼容别名无条件越界
    · sample_data0/1/2 = sample_data_packed[11:0]/[23:12]/[35:24]
    · 但 packed 宽度是 N_ADC*12 ⇒ N_ADC<3 时索引越界
    · 实测（临时 tb，N_ADC=2）：sample_data2 = xx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
2026-09-20 fix + docs: K-89 别名越界 + K-86 四大件参数 + 第二周计划 v2（含出声链）
    一、代码修复（我导致的 + 队友需要的）
    1. K-89 修复：adc_farm 兼容别名无条件越界
    · 原：assign sample_data0/1/2 = sample_data_packed[11:0]/[23:12]/[35:24]
    而 packed 宽度 = N_ADC*12 ⇒ N_ADC<3 时索引越界
    · 实测（临时 tb，N_ADC=2）：sample_data2 = xxx
    · 修：别名改为 generate 保护 —— 固定 3 片宽的 sample_data_alias[35:0]，
    g < N_ADC 时接 packed[g*12 +: 12]，否则接 12'd0（不越界）
    · 验证：N_ADC=2 ⇒ data2=000（原 xxx）、data0/data1 正常；N_ADC=3 仍 PASS；回归 25/25
    2. K-86：oscillator_ban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
    [adc_farm.sv, oscillator_bank.v]
2026-09-21 docs(week2): 统一三处口径不一致
    - README: 队友仍不推进 -> 已大幅推进(乙 w3b / 丙 adc_farm); tb_all 13/13->25/25, mutation 18/18->22/22 caught
    - README: 标注 T29~T31 编号已被本周新任务复用(原投板三件套已作废)
    - 任务清单: 17->38 项(编号唯一); T59 在 A/F 两组重复, 合并到 F 组并标记已完成
    - 分工: 背景段'队友推进缓慢'作废; 索引 T29~T53 -> T29~T63; 基线数 25/25 与 22/22
2026-09-21 T47: acquisition chain into Gowin project; fix K-91 (calib never synthesised)
    K-90 resolved: adc_farm/calib/debounce were in NO Gowin project, so they had
    simulation evidence only. Added them (plus mcp3208_driver/scanner) to
    bringup/synth_check.gprj and actually INSTANTIATED them in synth_check_top.v,
    because merely listing a file is not evidence (K-46).
    That immediately caught K-91: calib.sv used SystemVerilog size casts N'(expr)
    in 4 places. iverilog accepts them (so tb_calib was always green), but Gowin
    compiles .sv as Verilog-2001 and reported EX3863 x4 + EX3928, DROPPING the whole
    module. Replaced with width-ed localparam vectors (pure syntax, no behaviour
    change; also noted that in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
    [calib.sv, synth_check_top.v]
2026-09-21 docs(week2): K-91/K-90 into 分工 and 队友反馈
    - 分工 §2.1: adc_farm/calib/debounce 综合缺口已补; 记录 K-91 与资源占用
    - 给队友的审查反馈: 新增 K-91 (SV 强制转换 => Gowin 丢弃整个模块) 与
    K-90 的实测资源表; 纪律 '.sv 里不用 SV 专有构造, 判据=真跑一次综合'
2026-09-21 T54: note_manager.v (32-voice allocation) + watchdog for tb_all
    New: rtl/w3b/note_manager.v -- 32-voice allocation / stealing / release /
    parameter update, per W3 interface freeze table. This is the first block of
    the week-2 'make the board actually sound' chain (top.v still outputs silence;
    metronome/drum/looper all depend on this module).
    Three real bugs found while writing the acceptance test:
    1. pool_mask used always @(*) but degenerated to pure constants when
    RESERVED_N==0 (the default) => iverilog: '@* found no sensitivities so it
    will never trigger' => block never ran => mask stuck at 0 => NOTHING ever
    allocated. Gowin folds it correctly, so sim and synth disagreed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
    [note_manager.v, synth_check_top.v]
2026-09-21 T55+T56: de-stub oscillator_bank (64 lanes) and tdm_render_mixer
    oscillator_bank: 64 independent phase accumulators (generate-expanded so the
    count is verifiable in the netlist) sharing ONE 512x16 wavetable pROM over TDM
    (66 cycles/frame, 15x margin inside the 1024-cycle budget). Self-written DDS,
    no vendor DDS IP -- K-83 showed the IP would eat 97% of BSRAM.
    tdm_render_mixer: sums the OSC_PER_VOICE lanes per voice, multiplies by that
    voice's Q0.16 envelope through a SINGLE time-shared multiplier, accumulates and
    saturates to signed 24. Synthesis confirms exactly 1 DSP (not 32/64).
    Real bugs found and fixed while testing (all mine):
    K-96 synth_check_top tied voice_active_i to a consta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
    [oscillator_bank.v, synth_check_top.v, tdm_render_mixer.v]
2026-09-21 mutation_test: add -File/-Changed selection, concurrency lock, crash recovery
    - -File <substr> / -Changed: run only the mutants whose target file matches.
    Each mutant costs ~109 s (it runs the whole 28-bench regression), so all 37
    take ~67 min; a w3b-only change only needs M23..M37 (~27 min).
    - Concurrency lock (pid-based, auto-reclaims a stale lock): two runs would
    otherwise fight over the same files. This actually happened -- a -Filter run
    overlapped a full run and left M25's mutation in note_manager.v.
    - Crash recovery: a killed run leaves a mutation behind AND its .bak. The next
    run used to SKIP that mutant (anchor already mutated) and then run its
    clean-up regression on MU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
2026-09-21 T57: wire the real sound chain into top.v (board finally makes sound)
    top.v used to drive sample_mono = 0 -- silence -- while every simulation still
    passed, so the board could never make a sound no matter how green the suite was.
    It now instantiates the real chain:
    note_manager -> oscillator_bank (64 lanes) -> tdm_render_mixer -> i2s_tx
    plus a power-on self-test chord (A4 + C#5 + E5) driven through the ordinary note
    path, so 'the chain works on real silicon' needs no sensors.
    Evidence (independent of the DUT):
    HP_DIN now toggles 42958 times instead of sitting at 0
    external FFT on the captured samples: 441.07 / 560.28 / 655.65 Hz
    expected A4 440.000 / C#5 554.365 / E5 659.255, bin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
    [top_sound_samples.csv]
2026-09-21 T66: fix K-103 -- pipeline note_manager's candidate scan (Fmax 8.4 -> 58.6 MHz)
    K-103: after T57 wired the sound chain into top.v, the delivery top no longer met
    timing -- Actual Fmax fell from 55.96 MHz to 8.424 MHz with 1408 setup-violated
    endpoints and TNS -135600 ns. All 25 worst paths were inside u_note_manager
    (age_r -> phase_r CE, slack -98.7 ns, data delay 118.5 ns).
    Cause: the three-level candidate selection (free -> lowest releasing envelope ->
    oldest) was one long COMBINATIONAL priority chain. Levels 2 and 3 fed their own
    running best back into the next iteration, so synthesis could not parallelise it
    -- about 96 logic levels, and its result drove 32x32-bit phase_r clock enable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
    [note_manager.v]
2026-09-21 docs: note_manager latency contract 4 -> 34 cycles (K-103 fix), plus K-104/K-105
    W3 interface freeze table section 4: note_manager latency is now
    '<= POLY_TARGET + 2' (34 cycles at POLY_TARGET=32, i.e. 0.68 us), changed from
    '<= 4 cycles'. No port changed, so the interface itself is untouched -- only the
    waiting count in testbenches.
    Why it is acceptable, quantified:
    * adsr samples 'gate' only on sample_tick_i (once per 1024 cycles), so as long
    as allocation finishes within a frame the gate still takes effect on exactly
    the same sample -> perceived latency unchanged.
    * K-44 leaves 785 cycles for the synth chain; this uses 34 (4.3%).
    * polyphony untouched: still 32 voices / 64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
2026-09-21 docs(week2): list exactly which teammate files I changed (for the team chat)
    Answers 'what did you touch of ours'. Derived from git, not from memory:
    git log --author=Hokuu --since=2026-09-19 --name-only
    Four teammate files were touched (2 from smellripple, 2 from cyxxxx):
    rtl/drivers/adc_farm.sv N_ADC parameterised for 5-6 boards (K-85);
    then fixed my own alias out-of-range bug (K-89).
    sample_data0/1/2 kept as aliases -> no tb changes.
    rtl/drivers/calib.sv K-91: SV size casts made Gowin DROP the whole
    module (EX3928) while iverilog accepted them, so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
2026-09-21 T62 + gitignore + M32 re-point
    T62: bringup/05-焊接与通电检查清单.md -- a checkable soldering/power-up
    checklist for both hand boards, written while the boards are actually being
    soldered. Covers the three iron rules (power first, never plug the FPGA in,
    inspect for bridges), a per-step order with a measurement after each step, and
    the two documented traps:
    * E9/E10: R11 (OE pull-up) MUST be fitted, R12 (LE pull-up) should NOT be --
    they point in opposite directions. Fitting R12 makes LE high during
    configuration, which can flash a random LED (K-64).
    * K-65: SPI_1 and LED_1 are BOTH 8-pin XH2.54 with DIFFERENT pinouts, and the
    real netlist says SPI_1 has no 3V3 (po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
2026-09-21 evidence: regenerate from clean RTL after the full 40-mutant run
    40/40 caught, 0 leaks, 0 skipped, exit 0 -- the last action of the mutation
    runner is always a clean regression, so these logs are from unmutated code.
    M32 is now 'caught' (it used to be reported as an invalid mutant whose source
    did not compile; see K-105).
    [top_sound_samples.csv]
2026-09-21 第二周 C 组：接通出声链 + 音乐时钟 beat_gen + 文档口径修正
    一个周期的完整内容，压缩为单次提交。
    【C 组·接通出声链】板子真的会出声了
    * T54 note_manager.v 32 voice 分配/抢占/释放/参数更新（抓到 3 个真 bug）
    * T55 oscillator_bank 去桩：64 路独立相位累加器 + 共享 pROM
    * T56 tdm_render_mixer 去桩：TDM 共享乘法器 + 饱和（只占 1 个 DSP）
    * T57 top.v 撤静音（原本 sample_mono = 0）
    * T66 修 K-103 时序崩溃：Actual Fmax 8.424 -> 58.610 MHz，0 违规
    * 实测 FFT 441.07 / 560.28 / 655.65 Hz（期望 A4 / C#5 / E5）
    * 资源 LUT 12019 / FF 5464 / BSRAM 1 /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
    [beat_gen.v, synth_check_top.v]
2026-09-21 K-106 fix: make event-queue overflow observable (+ depth 16 -> 32)
    The dangerous part of this bug was never "one note is lost" -- it was that a
    lost note_off hangs a note forever, which is exactly the failure mode T38
    exists to prevent. And it happened SILENTLY: fifo_push = note_valid_i &&
    !fifo_full reported nothing at all.
    Worst-case burst is 16 keys + 1 metronome + 1 drum machine = 18, which the
    old depth of 16 could not hold (the "one event per axis per frame" reasoning
    simply forgot the automatic features).
    Four things, because depth and observability are ORTHOGONAL:
    * FIFO_DEPTH 16 -> 32 -- reduces the PROBABILITY of loss
    * event_lost_o (sticky) -- makes loss VIS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
    [note_manager.v, synth_check_top.v]
2026-09-22 T33: metronome (synthetic click on the event path) + perc_env_bank
    Two new W3c modules. The metronome is not a second audio path: it is "an
    automatic performer" that emits the SAME note_evt_t events a finger would, so
    there is zero new audio routing and zero new compliance surface.
    perc_env_bank.v exists because envelope_bank/adsr CANNOT make a click. adsr is
    an ADSR: it decays to sustain and then STOPS, so even a huge DECAY_STEP only
    reaches sustain sooner -- the note keeps sounding until note_off. With its
    defaults, peak->sustain takes (51200-12800)/4 = 9600 sample ticks ~= 197 ms,
    while a click wants 10-20 ms. So this is a different MODEL, not a wrong
    parameter. It is a NEW file: te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
    [metronome.v, perc_env_bank.v, synth_check_top.v]
2026-09-22 第二周设计文档批次：Looper 控制逻辑 / 曲谱自动演奏 / top.v 集成方案 / 进度小结
    本周期（2026-09-22 下午）全部是【设计文档】，没有改任何 RTL。
    新增文档
    * files/20-代码/Looper控制逻辑设计.md
    控制面设计（区别于已有的"数据面"设计）：
    录 / 选段回放 / 随时停止 / 只删一层（=替换）/ 添加新层 + 串口屏界面。
    调研了现实 looper（BOSS RC-1 单键多手势、RC-600 多轨），映射到我们的
    多层结构。最大简化：删除 = 清空某一层（5 个寄存器清零），添加 = 换一层录。
    记录用户拍板：只删一层、不做二次确认（改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
2026-09-22 T33b: port uart_rx (score-download front end) + fix a real test blind spot
    rtl/w3c/uart_rx.v is ported from an already-working project
    (Desktop/FPGA/ADDA/src/uart_rx.v, 8N1). Only two things changed:
    * reset made SYNCHRONOUS (freeze-table convention 2 requires one reset
    style; the original used an async reset, which is legal but inconsistent)
    * clk_cnt <= 6'd0 -> 16'd0 (the register is 16 bits; the literal was
    harmless but misleading)
    The state machine itself is untouched -- it was already verified.
    tb/w3c/tb_uart_rx.sv, 24 judgements. The original tb only used BAUD_DIV=10
    (an accelerated value), so the REAL baud rate had never been tested; this one
    runs at BAUD_DIV=434 (11520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
    [synth_check_top.v, uart_rx.v]
2026-09-22 第二周：曲谱/蓝牙/上位机规划 + 板卡定案 + 工具修复 + 换板 RTL 改动
    == 板卡定案（Tang Console 60K）==
    - 总账新增 §〇之二：含换板必改的 3 处差异
    (i2s JUSTIFY / PA_EN 语义 / BANK9 必须 1.5V)
    - 新增 U-24~U-29 待办
    == 换板 RTL 改动（U-24/U-25）==
    - i2s_tx.v: JUSTIFY 默认 1 -> 0 (MAX98357A 是标准 I2S 左对齐)
    - top.v: 例化处显式传 .JUSTIFY(0) <- 原来显式传 1，只改默认值不生效
    - top.v: PA_EN 语义变更 —— Console 无此功放使能脚，该网络接 SD_MODE
    做法: 不删端口/不改 .cst，只把驱动源变常量 + 保留 PA_ON_AFTER_RESET 开关
    == 工具修复（实测发现的真缺陷）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
    [Keyboard Swidget.stl, obj_1_Object_1.stl, top_sound_samples.csv, 左手板.step, 左手板单板.step, 键帽1.0.SLDPRT, 键帽1.0.STEP]
2026-09-22 丙线第二周验收硬化：T52(A4b→A4c) + T48(pROM 变体编译进回归) + perc_env_bank 补 M60 + 新增 master_mix(主音量+静音斜坡) 及 M61~M64 变异体
2026-09-23 ESP32 通路 + W3a 语义层 + 板卡修复：本周主线一并入库
    【ESP32 通路（另一条线）】
    - 模式 A 固件：SPP 纯透传 + 9N 对齐 + 回环自测工具
    - 模式 B：二级水池 + 离线算术校验器
    - 串口屏驱动（TJC T1 2.0 寸）+ 编译开关
    - 首次编译通过（双模式）：修 5 个编译期/配置期真问题
    - esp32/ 工程目录入库；交接文档两版；引脚统一到 Console 60K
    - ESP32-S3 BLE 版固件（透传 + 水池 + GATT 属性表 0xABF0~0xABF4）
    - 串口屏控件清单 + 上位机使用说明（编码定案 UTF-8）
    - ESP32 侧接续准备（唯一对接点 = evt_merge 源 A）
    【本周其他主线】
    - U-18/U-7 play_seq（曲谱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
    [top_m0_pa_trace.csv]
2026-09-23 fix(变异测试): 修正 perc_env_bank/master_mix 变异体编号 M60~M64 -> M81~M85，避开与 play_seq/evt_merge 的撞号
    - M81: perc_env_bank decay 不终止
    - M82~M85: master_mix 增益 ramp/缩放/valid/复位静音
    - 基于远端 main 最新 mutation_test.ps1（76 变异体）追加，保留 Hokuu 新增的 M59~M76
2026-09-23 fix(top): 基于 main 最新(2626462)重新接入 master_mix，消除合并冲突
    - 原 PR4 的 top.v 基于 dd5dd08 旧基线，会覆盖 Hokuu 在 2626462 的 top.v 改动(+142/-34)
    - 现改为在 main 最新 top.v 的 tdm_render_mixer→sample_r 之间插入 master_mix
    - 相对 main 仅 +26/-2 行，零文本冲突
    - 已验证：iverilog 编译通过 + tb_top_sound PASS（三音都在、deadline_fault 恒 0）
2026-09-23 第二周 W3a 采集链完成 + 合并丙线 master_mix + 板卡实测校正
    【W3a 采集链：按琴键出声】
    - 新增 rtl/w3a/{axis_map, axis_snapshot, event_extract, param_extract}.v + 对应 tb
    * axis_map 15/15 轴位→phase_inc（16 轴全表 + 真实指板音高 + 双压插值）
    * axis_snapshot 15/15 16 轴原子快照 + 带符号 Δ（滑音/双音的原料）
    * event_extract 9/9 触发/迟滞/不应期 + 同帧多轴不丢（一拍一个轴的状态机）
    * param_extract 11/11 双阈值测速力度；结构上无任何音符输出端口
    - 全部接进 top.v：adc_farm(2片) + calib×2 → 语义层 → evt_merge 源A → note_manager
    * vel_upd_*/pit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
    [top_sound_samples.csv]
2026-09-23 端到端"按琴键出声"tb + 上电自动 tare + 修 K-121（ssh 不在 PATH）
    【① 端到端 tb：⭐ 上板前唯一的"整链真的通"证据】
    - 新增 tb/e2e/tb_e2e_key_to_sound.sv（5 条判据全过）
    ⚠️ 此前覆盖是分段的：各模块有自己的 tb，而 tb_top_sound(T57) 走
    SOURCE_A_SEL=1（演示和弦）=> "按下磁轴 ⇒ 出声"从未端到端验证过。
    实测：不按键 ⇒ 0 toggles；按下 ⇒ 2044；换另一片 ⇒ 2458；复位后无 X；
    松开 ⇒ 包络在降（release 通路通）。
    - ⭐ 复用队友已验证的 mcp3208_model，⛔ 换掉我自写的从机
    🔴 我先后写了两版从机（组合/下降沿输出），位对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
2026-09-23 上板前修复：极性顺序 / 开机误触发 / 演示和弦不停 + calib_span + LED 引脚
    【① 🔴 极性反相必须放在 calib【之前】（上板会"完全不能演奏"）】
    用户 2026-09-23 实测：松手 1.60V、触底 1.00V ⇒ 按下 raw【变小】。
    而 calib.v:148 内建假设"按下 ⇒ raw 变大"：
    prod = (raw > zero) ? (raw - zero) * gain : 0
    ⇒ tare 记下松手位后，松手与触底【都被钳成 0】⇒ 反相后 pos ≡ 4095
    ⇒ 永远触发、分不出按下 ⇒ 完全无法演奏。
    ⭐⭐ 两个改动单独都对、合起来错：INVERT_AXIS 单独 ✅、autotare 单独 ✅。
    更隐蔽的是：没 tare 时反而"正常"（zero=0）⇒ 加 auto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
    [calib_span.v, event_extract.v, tb_e2e_key_to_sound.sv]
2026-09-23 新增 07-Console 上机指南（2026-09-24 上板版）：按今晚新引脚表重写
    ⭐ 为什么新写一份（⛔ 不是改 06）:
    今晚引脚【全变了】—— 6 根 ADC 全部换 ball（为'每片 MISO+CS 同排左右'，
    扩展板好走线）+ LED 组从 PMOD 挪到 J9 ⇒ 旧接线表作废。
    ⚠️ 直接改 06 会让'9/23 白天打印的表'和文件对不上 ⇒ 另存一份、日期可辨。
    内容:
    · §2 完整接线表（⭐ 权威 = constr/top.cst，今晚刚改）
    - SPI 14 根：N1~N16，⭐ 每片 MISO|CS 同排左右
    - LED 8 根：N17~N24
    - 板载固定：clk/rst_n/I2S/PA_EN_n/heartbeat
    · §3 不上电检查（量电源电阻、核对 6 根线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
2026-09-23 回归 44/44 全过（SPI 端口改成 6 片预留向量 + 引脚重排后）
2026-09-23 PnR 证据（引脚重排后）：0 setup / 0 hold，Fmax 53.782 MHz，22 个新引脚 ball 全部核对一致
    引脚全重排后必须重跑（改 ball = 改物理约束）。
    结果：
    - exit 0，bitstream 已生成（21:39）
    - Setup / Hold 违规 0 / 0
    - Actual Fmax = 53.782 MHz（约束 50，余量 7.6%）
    - ⭐ 逐条核对：22 个新信号的 ball 与 constr/top.cst 完全一致
    （SPI 14 根 + LED 8 根）=> ⭐ 与上机指南 §2 的接线表对得上
    ⭐ 这就是明天接线表的【最终凭据】：PnR 报告的 ball == 指南 §2 == 实际约束。
2026-09-23 引脚重排：SPI 改 6 片预留向量 + 每片 MISO|CS 同排左右 + LED 组挪到 J9
    🔴 本提交是【补提交】—— 前面两个提交（0c2bf9f 回归证据 / 4439625 PnR 证据）
    只 add 了 sim/evidence/，⚠️ 忘了 add 源码。
    => 那两个提交的说明写"22 个 ball 核对一致"，而约束文件本身没进版本库
    —— 证据与代码脱节。若就这样 push，队友拉到的引脚表会和 PnR 证据对不上。
    ⭐ 本提交补上实质改动。PnR/回归本身有效（它们读的是工作区文件）。
    【用户要求（2026-09-23）】
    · "spi 也不止 3 根，最好留 5 根" → 最终定为 6 片：左手板1~4 + 右手板A/B
    · "m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
2026-09-23 W3a 标定链 + 阶段A验证 + 长任务方法 + 过时文档修正
    【本轮主线：calib_span 接入准备】
    - calib_span 补齐 tb（此前从未有过，交接文档误记为已通过）
    发现并修 3 个"静默卡死"真缺陷：
    ① S_SETTLE 无超时（adc_farm 停扫 or 操作者松手 ⇒ 永久卡住、无输出）
    ② S_VOTE 无超时（投票中途帧停）
    ③ S_NEXT 等 calib.busy，但 calib 走 err 分支时不拉 busy（探针实测二者物理互斥）
    修法：四处等待全加 WAIT_TIMEOUT_CLK + 超时走与正常失败同一条上报路
    + span_sent_r（因二者互斥，必须主动记录已发过）+ 删掉不可达的死代码分支
    - 新增 calib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
    [calib_autotare.v, calib_cmd.v, calib_span.v, tb_calib_autotare.sv, tb_calib_cmd.sv, tb_calib_span.sv]
2026-09-23 W3a 标定链：阶段B+C 全接进 top.v（含 uart_tx 新增 + 修 4 个真缺陷）
    【阶段B：calib_span 接进 top.v】
    - 例化 u_calib_span，raw_i 接 af0_pol（反相后、calib 前那一路）
    - cal_ch 同拍仲裁：sp_busy ? sp_ch : at_ch
    （calib 的 raw 是当拍输入，错一拍会把别的通道的值记成本通道的）
    - u_calib0/1 的 busy/err 从空连接改为接出（此前标定失败无法感知）
    【阶段C：串口通路全接】
    - top.v 新增 uart_rx(V14,入,PULL=UP) / uart_tx(U15,出)，LVCMOS33
    V14 属 BANK8、U15 属 BANK6，都不是 BANK9(1.5V)，与 AA13/Y14 不同
    - 例化 uart_rx / calib_cmd / evt_uart_rx，三者波特率同档 1 Mbps
    - 互锁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
2026-09-23 ESP32 通路：S3/BLE 版固件 + 串口屏三件套 + 上机指南 + 协议对接文档
    【新增：ESP32-S3 BLE 版固件（esp32/ble/，主推）】
    - GATT 属性表（UUID 照抄 ESP-IDF 官方 ble_spp_server）
    0xABF0 服务 / 0xABF1 收 / 0xABF2 发 / 0xABF3 CMD / 0xABF4 STAT
    - 9N 对齐（BLE 按 ATT 包投递，一帧可能被切成两包 => 必然截帧）
    - 三种 9 字节块（靠帧头区分）：0xA5 事件 / 0x00 总数 / 全A5 复位
    - 模式 B 二级水池（走 PSRAM，放得下整曲 104KB）=> 默认模式
    - 放水按 tick 限流（修 budget=64帧/2ms => 理论 32000 帧/s 这个真问题）
    - 修 total=0 真 bug（原来屏上一直显示 4820/0、进度条永远 0）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
    [ble_config.h, ble_main.c, bridge_config.h, bridge_main.c]
2026-09-24 新增 ESP32 线当前断点：上机入口 + 三个已知坑 + 两件未决事项
    用途：明天上机调试的起点，不是项目文档（那些已有）。
    核实到的事实（不凭印象）：
    · 我的分支 feat/s3-ble @ d6bc112 已推远端、工作区干净
    · 但 origin/main 仍是 c6aa509 —— BLE 版【还没进 main】
    （逐个 git cat-file 查过：ble_main.c / send_frames.py / 上机指南 /
    串口屏控件清单 / build.ps1 都不在 main 上）
    ⚠️ 并给了自查命令，让下个会话先验一遍
    内容：
    · 〇 一句话：代码文档都已推，下一步全卡在硬件
    · 一 分支与仓库状态（含"怎么确认在不在 main"的命令）
    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
2026-09-24 上板前准备批次：11 份设计文档 + 全量变异测试（88 caught / 0 LEAK）+ 上板操作卡
    ═══ 一、全量变异测试（⭐ 本轮核心验证）═══
    - 90 个变异体全部执行：✅ caught 88/88 · ✅ LEAK 0
    - 🔴 2 个 SKIP 已修复并复跑验证（M40 / M85，⭐ 两条根因【完全不同】）
    · M40：真·锚点过时（信号改名 mx_* -> mm_*）
    · M85：🔴 编码 —— 锚点含中文注释，脚本是无 BOM UTF-8，
    PowerShell 5.1 按 GBK 解码 ⇒ 锚点变乱码 ⇒ 静默 SKIP
    ⇒ ✅ 已固化：91 个变异体的 find/repl 现在全部纯 ASCII
    - ⭐ 证据落盘：sim/evidence/mutation_after_w3a_calib_chain.log
    ═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
2026-09-24 通知修正：纠正音色方案理解错误 + 2 处过时数字 + 加'先拉远端'
    详见本地 squash-history；本次仅文件：两份待发通知
2026-09-24 Console 器件型号确认 + K-124 力度修复 + 组合环修复 + 编码纪律
    ════════ 🔴 队友最需要的：Console 资料 ════════
    【器件型号（⭐ 已按实物核对 + PnR 验证通过）】
    - Gowin2026.gprj: pn 从 GW5AT-LV60PG484AC2/I1（基石板）
    → GW5AT-LV60PG484AC1/I0（Console 实物确认）
    - IDE 设置：Package = PBG484A · Device Version = B
    - PnR 在新型号下通过：exit 0 · 0 setup / 0 hold · Fmax 57.770 MHz
    - ⚠️ 踩坑：Gowin 的 .gprj 解析器会【扫注释里的器件料号】——
    注释里出现另一个料号 ⇒ "invalid project file"（已修）
    【上板操作卡（bringup/10-上板操作卡-20260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
    [top_sound_samples.csv]
2026-09-24 修复上机实测缺陷：小延时塌成 vTaskDelay(0) 导致看门狗触发
    上机实测（COM29, 2026-09-24）：Task watchdog 5s 触发，IDLE0(CPU0) 被
    饿死，栈回溯 task_drain @ ble_main.c:484 -> vTaskDelay。
    根因：CONFIG_FREERTOS_HZ=100（1 tick = 10ms），pdMS_TO_TICKS() 是整数
    除法 => 任何 <10ms 的值全部塌成 0 => vTaskDelay(0) 不真正让出 =>
    优先级 9 的任务被立刻调度回来 => 忙循环饿死同核 IDLE0 => IDLE 无法喂
    看门狗 => 5s 后 TWDT 必然触发。
    受害点（均为优先级 9，无条件空转）：
    - ble_main.c task_drain() pdMS_TO_TICKS(1) = 0
    - pool.c task_pool_pump() pdMS_TO_TICKS(2) = 0
    对策：ble_config.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
    [ble_config.h, ble_main.c]
2026-09-24 上机指南更正端口/esptool + 新增上机实测问题分析文档
    上机指南（只给傻瓜步骤与预期现象，不含分析）：
    - §二 新增【先查端口】命令：Get-PnpDevice 按 VID_303A 过滤。
    原因：本机 COM7/COM8 是蓝牙串行口，写死端口号会把固件往蓝牙口上烧；
    真实端口 COM29，且每次插拔可能变。全文 COM7 -> COM29。
    - §2.1 删掉跑不通的 python -m esptool flash_id（系统 python 无 esptool），
    改为直接看 chipid 输出里的 Embedded PSRAM 8MB。
    - COM8 为 USB-TTL 占位示例，本来已标注'换成你的'，未改动。
    新增 files/20-代码/ESP32上机实测问题分析-20260924.md（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
2026-09-24 合并 ESP32 BLE 分支 + 修"验收误报"超时 + 重写上板操作卡
    ════════ ⭐ ESP32 BLE 合并（feat/s3-ble）════════
    - esp32/ble/ 全套固件（ble_main.c / gatt_svc.c / hmi.c / pool.c / sdkconfig.defaults）
    - esp32/串口屏三件套（指令表 / 控件清单 / 上位机使用说明）+ esp32/上机指南.md
    - esp32/tools/send_frames.py + 4 份 ESP32 设计/交接文档
    - ⭐ 无冲突（main 动 FPGA 侧、BLE 动 ESP32 侧，零重叠）
    - ⭐ 顺带：esp32/ble/build.ps1 补 UTF-8 BOM（由编码守卫抓到）
    - ⭐ 两件"未决"结案：协议文档改"已实现记录" · 断点文档标已合并
    ════════ 🔴 修"验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
2026-09-24 修复 BLE 广播无法启动（3 个缺陷叠加）
    上机实测环境：ESP32-S3-DevKitC-1 / COM29 / ESP-IDF v5.5
    现象：手机扫描不到 "FPGA2026-Synth" —— 固件广播从未启动。
    定位到 3 个叠加缺陷：
    【缺陷 1】漏调 esp_bt_controller_mem_release(ESP_BT_MODE_CLASSIC_BT)
    现象：E BT_BTM: btm_ble_write_adv_enable_complete failed
    E blebridge: adv start failed: 0xD
    根因：S3 硬件只有 BLE，但 IDF 默认为经典蓝牙预留控制器内存；
    不释放 ⇒ 广播这类 activity 申请资源失败。
    依据：IDF 官方【每一个】BLE 例子（如 ble_ibeacon）都在
    esp_bt_controller_init() 之前调用这一行，本工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
    [ble_config.h, ble_main.c]
2026-09-24 上机记录：4 个缺陷的完整分析 + 指南补 BLE 连接实操
    问题分析文档（ESP32上机实测问题分析-20260924.md）重写，覆盖上机第一晚
    定位并修复的【4 个真缺陷】：
    缺陷 1 看门狗必然触发（已修 a310700）
    根因：CONFIG_FREERTOS_HZ=100 ⇒ pdMS_TO_TICKS(<10ms) 整数除法塌成 0
    ⇒ vTaskDelay(0) 不真正让出 ⇒ 优先级 9 任务忙循环饿死 IDLE0。
    受害：task_drain (ble_main.c:484)、task_pool_pump (pool.c)。
    含失败路径：我曾误判 HZ=1000，差点做架构级改动（已记为教训）。
    缺陷 2/3/4 BLE 广播从未启动（已修 c7d03ad，3 个缺陷叠加）
    A. 广播数据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
2026-09-24 新增 send_frames_ble.py：PC 侧 BLE 直连灌数据（绕开虚拟串口）
    背景
    ====
    2026-09-24 上机实测发现三条路径的行为差异：
    · 手机 App → BLE → ESP32 ✅ 通（ble_rx=9）
    · 桥界面发送框 → BLE → ESP32 ✅ 通（ble_rx=9）
    · 脚本 → COM11 → 桥 → ESP32 🔴 不通（ble_rx=0）
    根因：桥工具的 COM11 是懒连接的虚拟串口对，且不在 pyserial 的端口
    枚举里（能 open() 但数据不过去）⇒ 自动化灌数据走不通。
    ⭐ 本脚本用 bleak 库【直接走 BLE】，绕开虚拟串口与桥工具。
    内容
    ====
    esp32/tools/send_frames_ble.py
    · 载荷构造与 send_frames.py 完全一致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
2026-09-24 修正 sdkconfig.defaults：BLE 5.0 与 MAX_ACT 均为广播必需项（实测确认）
    上一个提交（bf9b39f 合并）后，我发现 sdkconfig.defaults 里留着两个
    "我声称已回退、实际没退"的配置项，于是尝试改回 IDF 默认。
    结果实测证明：⭐ 这两项【都是广播能工作的必要条件】，⛔ 不能回退。
    ⭐ 判定方法（最干净的一次对照）
    ================================
    固定【完全相同的代码】（git diff a98549b HEAD -- esp32/ble/ 为空），
    只改配置，观察日志有无 advertising as "FPGA2026-Synth"：
    BLE_50=n + MAX_ACT=6/ACL=4 ⇒ I advertising as "FPGA2026-Synth" ✅ 成功
    BLE_50=y + M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
2026-09-24 UART 上板打通：搬引脚/降波特率/K-126 发送队列/时序与诊断命令
    - UART 从板载搬到 J9 排针（D14/D15），波特率 1M -> 500k（整除无误差）
    - 修 K-126：回传加 uart_tx_fifo（轴号提示原来 100% 被丢）；
    再修其 cnt 双重赋值（每包多 1 字节、逐次累积）
    - 修 pos_probe：改四级流水（Fmax 50.011 -> 56.986 MHz）+ 2 个 BCD 比较器 bug
    - 新增诊断：'P'（回 pos 读数 + 通道号）、'V'（回 calib_span 内部状态）
    - 放宽 calib_span 稳定/投票容限并从 top.v 暴露；记录 K-126/K-127
    - 合并 PR #5 的 led_data.v + tb；补 PnR 证据（0/0 · Fmax 56.986 MHz）
    [calib_cmd.v, calib_span.v, led_data.v, pos_probe.v, span_probe.v, uart_tx_fifo.v]
2026-09-24 修复 'S' 只回 s 不回轴号（K-132）+ 帧周期口径更正（K-128）
    K-132 核心修复（calib_span.v）:
    - 根因: S_PROMPT 单拍离开, 而 SETTLE/VOTE/FIRE 都不清 need_press_o
    => 重试回到 S_PROMPT 时它本来就是 1 => 无 0->1 跳变
    => top.v 的 ev_need(上升沿检测) 不再产生 => 轴号永不回发
    - 修法: S_PROMPT 停 2 拍（新增 prompt_phase 标记）
    第1拍 need_press_o<=0（造下降沿）, 第2拍 <=1（干净上升沿）
    - 端到端验证（新增 tb_span_axis_over_uart, UART 线上实收字节）:
    修复前 s0!!!!!!!!!（轴号1次） / 修复后 s0!0!0!0!0!0!!（轴号6次）
    - 上板实测确认: s0!0!0!0!0!0!0!0!0!（轴号9次）=> 修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
    [adc_farm.sv, calib_span.v, event_extract.v, mcp3208_model.sv, tb_span_alignment_gap.sv, tb_span_axis_over_uart.sv, tb_span_cross_channel.sv, tb_span_need_press_width.sv]
2026-09-25 自动功能集成：源A三级仲裁(seq_arb) + 纯合成鼓机(drum_gen) + 外置DAC通路
    ═══ 新增模块（D 组自动功能）═══
    - rtl/w3c/seq_arb.v —— 源 A 三级仲裁（手弹/曲谱/演示）
    · 补 top.v:1520 的 TODO（原文：源A要有3个来源 => 应改成 evt_merge 前再加一级仲裁）
    · 复用 evt_merge 已验证的环形 FIFO 手法（同拍不丢、轮转不饿死、溢出可见）
    · 演示让位：有别的源在发时自检和弦不参与（不抢演奏 voice）
    · 可观测：collision/merged/drop/overflow + 每源计数
    - rtl/w3c/drum_gen.v —— 纯合成鼓机（Kick/Snare/HiHat/Clap）
    · 16 步音序器【合并在内】（用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
    [drum_gen.v, seq_arb.v, tb_span_multiaxis_noise.sv, tb_top_m0.sv, tb_top_sound.sv]
2026-09-25 丙线 LED 链：tlc5916_bank（CH→OUT 重映射+共享总线三片驱动）+ tb + 接入 top.v + 变异体 M126/M127
2026-09-25 丙线 uart_ui：串口屏(TJC X2)人机交互层 + tb + 变异体 M128~M131
2026-09-25 T43: 完成 Test Mode 4/8/16/32 声部频谱验收
    实现 test_mode_ctrl 的声部译码、单振荡器通道选择和 FFT bin 对齐频率计划；补齐控制级与真实 wavetable FFT testbench、峰值验收脚本及五个对应变异体。
    验证：普通回归 50/50 PASS；四档 FFT 峰数精确为 4/8/16/32；MTM1-MTM5 全部 caught；Gowin PnR 0 setup/0 hold，Fmax 57.770 MHz。
    # Conflicts:
    # sim/evidence/gowin_build.log
    [test_mode_n16.csv, test_mode_n16_peaks.csv, test_mode_n16_spectrum.csv, test_mode_n32.csv, test_mode_n32_peaks.csv, test_mode_n32_spectrum.csv, test_mode_n4.csv, test_mode_n4_peaks.csv]
2026-09-25 feat: wire UART test mode into synth top
2026-09-25 fix(文档): 修复两处断链的交叉引用 (#7)
2026-09-25 上板验证批次: 复音归一化 + 时序流水 + 音高表重排 + 事件对齐 + 节拍器/迟滞修复
    ## 一、上板暴露的问题与修复
    1. 复音削顶(3音失真28.7%) -> 归一化 1/sqrt(N) + 软限幅(基准70/限幅70%)
    探针实测: 贴顶率 24.2% -> 0.0%, 峰值 89% 满幅
    2. 归一化拖垮时序(Fmax 39.5 < 50) -> 打 3 级流水 + valid 同步延时
    Fmax 恢复 51.146 MHz, 0 setup / 0 hold
    3. 音高不符合直觉 -> 按【物理位置<->轴号】实测锚定重排 fb_inc
    常量改名 FB_AXn -> 音名(旧名会让人误以为'轴7就该是F3')
    4. 事件 valid 与音高差一拍 -> am_vld_out/am_axis_out 对齐 am_inc
    5. 节拍器沉闷 -> 常量小1000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
    [axis_map.v, dac_tone_top.v, metronome.v, tb_axis_map.sv, tb_dac_tone_top.sv, tb_e2e_key_to_sound.sv, tb_export_key_wav.sv]
2026-09-26 feat(vibrato): 右手板 ADC 控制 + 颤音 LFO 接入 (T18)
    新增 right_analog_ctrl(P4 右手板 CH2=深度/CH3=速率) 与 vibrato_lfo(连续相位增量调制，无相位复位咔声)，经 top.v 接入 oscillator_bank；RIGHT_ADC_ENABLE 默认 0，未接线时控制强制归零。附 w3a/w3b 三个 testbench 及仿真证据，更新第二周计划与已知问题清单。
    [right_analog_ctrl.v, tb_right_analog_ctrl.sv, vibrato_lfo.v]
2026-09-26 feat(volume): 接入右手 CH1 对数主音量 (T17)
2026-09-26 docs(board): 校正 Console 引脚与串口说明
2026-09-26 修复"水怪低吼"真因（开机竞态）+ 增益链定案 + 缺口清单校正
    上板实测驱动的排查与修复。回归 72/72 · PnR 0 setup / 0 hold。
    ## 一、🔴 真因：开机竞态 —— 8 个假 note_on 导致 voice 恒响
    ### 症状
    用户上板：*"只有那个空灵沉闷的水怪低吼，也就是底噪"* +
    示波器 *"波动，最高 1.4V，有时有负值"* + *"单键声音很小"*
    ### 诊断（六个探针，全部实测）
    dbg_idle 静音时 sample_mono 非零 100%、峰值 34.8%
    dbg_dc 逐级追踪：mixer 输出即 30% => 源头在 mixer 上游
    dbg_noteoff note_manager 收 on=11 / off=3（多 8 个 on）
    dbg_pos 稳态下 16 轴 pos 全 0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
    [metronome.v, note_manager.v, oscillator_bank.v, param_extract.v, tdm_render_mixer.v]
2026-09-27 docs: 补全 K-149 中 RTL 路径缺失的 rtl/ 前缀
    check_doc_refs.py 报 3 处硬错误：w3a/param_extract.v、
    w3b/oscillator_bank.v、w3b/tdm_render_mixer.v 缺 rtl/ 前缀。
    一并补上同列表里 top.v 的前缀。
2026-09-27 钢琴模式实装: kb_inc 真实音高表 + 烧录默认钢琴模式
    ## 背景（用户上板 + 需求）
    用户: "我们肯定需要得到一个会消失的声音啊，不可能让他一直在后面占着位置"
    "既保留钢琴模式，又保留指板模式。并且烧录的时候优先烧录钢琴模式"
    "钢琴模式和指板模式的音高表也不一样，这个地方有能切换的吗"
    ## 问题 1: 钢琴模式完全不可用（我实测发现）
    队友 5d79ff6 (T15) 引入 play_mode_ctrl 时，kb_inc 仍是 key_inc(ti) 半音阶梯占位表。
    我算了它的实际输出（build/exp/check_kb_inc.py）:
    轴 0: 11.92 Hz (G-1) 轴 15: 28.35 Hz (A#0)
    全部 16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
    [axis_map.v, uart_ui.v]
2026-09-27 feat(c): A1 test-mode UI switch on serial screen (touch control 2)
2026-09-28 修复 B2「偶发尖音」+ B3「挂音」：11 项 RTL 修复 + 判据入库 + 审计文档
    ═══ B2 尖音（上板确认已解决）═══
    根因：4:1 硬膝限幅器在阈值(95% FS)处的【折点】产生谐波
    · 代码 :480-493 的量化依据假设「两 lane 偶尔相位对齐」=> 只留 31% 余量
    · 但失谐让两 lane【周期性 100% 同相】=> 相干叠加 x2 => 峰值 138% 满幅
    · => 每个拍峰都越过阈值 => 硬膝折点 => 谐波 => 用户听到「音色不同的音」
    · 周期 = 拍频 T=256/f（C3 1.957s 误差 2.1%；D3 1.744s 误差 0.2%）
    · 波形实测：离群毛刺【100% 只在高幅度区】，低幅度区 0 个
    修法：C1 连续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
    [test_mode_n16.csv, test_mode_n32.csv, test_mode_n4.csv, test_mode_n8.csv, top_sound_samples.csv]
2026-09-28 失谐音量平衡方案 + 修 CI 文档交叉引用
    【一】失谐音量平衡-方案-20260928.md（新增，⭐ 按用户选择，代码暂未改）
    · 问题：失谐两个 lane【波形完全相同】=> 反相时 100% 抵消
    => ① 长音音量周期性起伏 ② 起音音量随机
    · 方案（用户已选「最稳」）：vs = (13*L0 + 3*L1) >> 4
    w0=0.8125 / w1=0.1875
    同相电平 = 1.000（⭐ 响度不变）
    反相电平 = 0.625（⭐ 摆幅从 ∞ dB 降到 4.1 dB）
    ⭐ 波形不变 => 音色不变（⛔ 不像上次改 timbre 那样）
    · 含：候选对比表 / 实施细节 / 5 条实现注意 / 验证计划（含非空洞性要求）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
2026-09-28 位置式力度反馈 + FMAX 修复（slack 2 皮秒 -> 1.289 ns）+ 构建脚本缺陷修复
    一、位置式力度反馈（用户需求：音量实时跟随按键位置，抬起后冻结，松手自然衰减）
    · rtl/top.v +207/-31：位置式力度流（8 轴轮转 / 死区 16 / 下限 64）
    + 起音力度也位置式 + TRIG_TH 192->64 · REL_TH 80->32
    · rtl/w3b/note_manager.v +26/-8：(d) 段去掉"只允许调大" => 可增可减
    · tb/w3b/tb_vel_pos_follow.sv：新增判据 18 条（含非空洞性）
    · files/20-代码/位置式力度-方案-20260928.md · 失谐音量平衡-方案-20260928.md
    ⭐ 已上板确认：判据 1~5 全部通过
    二、FMAX 修复（根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
    [note_manager.v, tdm_render_mixer.v]
2026-09-28 失谐音量平衡 + FMAX 修复 + 构建脚本缺陷修复 + vu_* 判据补齐 + 节拍器方案
    一、失谐音量平衡（Minimal-A，用户裁定 1.125:0.875）
    · rtl/w3b/tdm_render_mixer.v：lane 加权 (9L0+7L1)>>4，用代数恒等式
    9L0+7L1 = 8(L0+L1)+(L0-L1) 实现 ⇒ 零乘法器（DSP 回到 7）
    + 参数自检（防 LANE_W0/W1 静默失效）
    · rtl/top.v：新增 parameter DETUNE_SH=9 + 透传给 oscillator_bank
    · tb/w3b/tb_tdm_render_mixer.sv：3 条派生值更新 + 新增 3b 反相深度判据
    实测：反相/同相 = 0.12471 ≈ 1/8（-18.08 dB）· 0 setup/0 hold · Fmax 55.119 MHz
    二、FMAX 修复（slack 0.002 -> 1.289 ns，已上板确认听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
    [top_sound_samples.csv]
2026-09-29 丙线: FPGA 侧串口屏(TJC X2) UI 控件规划文档
    与 uart_ui.v 已实现的返回解析契约一一对应:
    触摸控件 0 = 模式切换, 2 = Test Mode 切档, 数值变量 1 = 起始音.
    厘清三条独立串口通路, 避免与 ESP32 通路(2寸屏)混淆.
2026-09-29 W3a/W3b：串口切换音色 + looper 退出修复 + 诊断证据补齐
    音色（本周期对外可见的改动）：
    - oscillator_bank 新增 VEL_TIMBRE_BLEND（默认 0）：力度不再参与音色选择，
    音色只由 timbre 决定；关闭混合时固定用 rom_hard
    （实测：rom_soft 四块完全相同且峰值仅 16384；rom_hard 满幅 32767 且四块互不相同）
    - calib_cmd 新增 'I' 命令（CMD_TIMBRE = 0x49），串口可循环切换 4 个音色
    - top.v 新增 timbre_sel_r，接到 note_manager 的 default_timbre_i
    其它：
    - looper：修复 'C' 清空请求导致的挂音（唯一出口 + leave_to 状态机）
    - 诊断与证据：pos_probe、DPOS_DIAG 门控、bitst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
    [test_mode_n16.csv, test_mode_n32.csv, test_mode_n4.csv, test_mode_n8.csv, top_sound_samples.csv]
2026-09-29 looper 事件通路改造与鼓机收尾（待上板验证）
    - looper：事件加来源标记；note_off 按来源隔离（seq_arb / evt_merge / note_manager）
    - looper：回放记两端点（note_on=起点、note_off=终点），按 tick 线性插值力度与音高
    - note_manager：voice 复用与抢占都按来源判定（手弹与回放同轴共存）
    - looper：ep_mem 收拢为单一写口，满足 Gowin BSRAM 推断（原 3 个写地址表达式推不出）
    - 鼓机：第 4 件乐器 clap 改 Tom（约 150 Hz / vel 190）；串口 'D' 切节奏型；源 B 固定音色（在 build/drum 分支，另行 cherry-pick）
    - 变异锚点：修复随源码演进失效的锚点，并注册 2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
    [test_mode_n16.csv, test_mode_n16_peaks.csv, test_mode_n16_spectrum.csv, test_mode_n32.csv, test_mode_n32_peaks.csv, test_mode_n32_spectrum.csv, test_mode_n4.csv, test_mode_n4_peaks.csv]
2026-09-29 总账 §25.7：push 完成记录 —— 合并队友 HDMI 参考提交无冲突、37 个提交压成 1 个（7863b40，措辞待上板验证）、HEAD 与 origin/main 一致、备份 tag 与 bundle 已就位且 tag 未泄露
2026-09-29 looper：on_open_r 泄漏 —— ST_REC 的两个入口清零 on_open_r（待上板验证）
    改动：
    - rtl/w3c/looper.v：在 ST_REC 的两个入口（br_rec_w 与 ST_LCLOSE 的 LEAVE_REC）
    各加一行 on_open_r <= 16'd0;
    - tb/w3c/tb_looper.sv：新增判据 stale_on_open（只增不改）
    根因（按代码逐条确认）：录制中收到 clear 时 br_leave_w 为假（它要求
    state == ST_HOLD），于是走 br_clear_w 分支直接回 ST_IDLE —— 该分支既不补发
    note_off 也不清 on_open_r，那个还按着的音的 on_addr_r（上一遍录音的地址）就
    留到了下一遍录音。下一次录制期间再松开该键，这条没有前置 note_on 的 note_off
    因 on_op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
2026-09-29 新增《端到端延迟预算-重算-20260930》：从现行 RTL 逐段重算（①ADC 采样时隙 500us ②ADC 事务+帧收齐 196.18us ③事件提取 0.42us ④仲裁与分配 1.02us ⑤ADSR+TDM+混音 43.10us ⑥效果器无实例 ⑦I2S 18.64us）；合计最坏 759.36us（≤10ms 有 13.2 倍余量）；并列出与旧文档的 12 条矛盾（ADSR 起振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
2026-09-29 总账 §25.8：U-5 延迟预算重算结论 —— ≤10ms 已能从 RTL 证明（通路 A 759.36us 余量 13.2 倍 / 通路 B 62.88us 159 倍）；结构性发现现行有两条控制通路（轴位过 ADC、拨弦 LM393 直采）；确定性无抖动在轴位口径不成立（极差 692.6us）需裁定；并记 RTL 打脸旧文档的关键 5 条（ADC 事务 196us、ADSR 起振晚一帧、n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
2026-09-29 K-169：起音相位复位改挂 note_on 事件边沿（待上板验证）
    - rtl/w3b/oscillator_bank.v：新增每 voice 输入 voice_phase_rst_i
    （= note_manager.voice_retrig_reset_o，即每 voice 的 note_on 事件）。
    起音相位复位判据由「voice_active 电平上升沿」改为「事件边沿 || 电平上升沿」；
    事件边沿是权威触发，旧电平判据保留为向后兼容兜底
    （老例化不接新端口 => z => 按 === 1'b1 解码为 0 => 行为与改动前一致）。
    - rtl/top.v：u_oscillator_bank 接上 .voice_phase_rst_i(nm_retrig_reset)，
    与 envelope_bank 的 retrig_reset_i 同源 => 包络清零与相位复位由同一事件驱动。
    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
    [note_manager.v, oscillator_bank.v]
2026-09-29 鼓机：分类改 4 类（大鼓/小鼓/嗵鼓/镲）、串口 'D' 切节奏型、源 B 固定音色（待上板验证）
    - drum_gen：第 4 件乐器 clap 改 Tom（约 150 Hz / vel 190）；节奏型表相应调整
    - calib_cmd：新增 CMD_DRUM_PATTERN = 8'h44（'D'），单周期请求脉冲
    - top：DRUM_PATTERN_ID 由编译期参数改为运行时寄存器 drum_pattern_r（复位值 = 参数）
    - top：源 B 给固定音色 DRUM_TIMBRE = 2'd2（鼓机不再跟随键盘音色）
    - tb：tb_calib_cmd 新增 'D' 判据；tb_drum_gen 扩充；新增 tb_drum_timbre_top
    证据：三个聚焦 tb 均通过 1/1（tb_drum_gen / tb_calib_cmd / tb_drum_timbre_top）
    注意：全量回归与 PnR 尚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
2026-09-29 证据：K-169 与锚点修复的聚焦 tb 日志（tb_note_manager / tb_oscillator_bank / tb_retrig_reset_span 等）
2026-09-29 新增鼓机宽带噪声波表（第 10 张 pROM）并按保留轴位路由（待上板验证）
    - tools/gen_t31b_wavetable.py：新增 generate_noise_table()（整数谐波 1..512 ×
    随机相位 × 等幅 ⇒ 平坦谱、天然周期安全、天然零直流），固定种子 0x5EED2026；
    新增零直流 / 峰值 / 环绕台阶的自检与统计打印。
    - rtl/w3b/wavetable_bank.v（生成物）：新增第 10 个 pROM rom_noise_inst 与
    sample_noise_o 输出（9 → 10 个 pROM）。
    - rtl/w3b/oscillator_bank.v：新增 voice_drum_i（每 voice 1 位）与 1 拍响应标签
    resp_drum_q，鼓 voice 改选噪声表；悬空端口按"非鼓"解码（老 tb 行为不变）。
    - rtl/w3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
    [note_manager.v, oscillator_bank.v, wavetable_bank.v]
2026-09-29 变异测试：7 个失效锚点重新定位 + 新注册 M135/M136（135/135 锚点字节级复验）
    - M25/M26/M27：A3' 给这三个 if 各加了一行同源判据，旧锚点结尾的 "))" 已不存在
    ⇒ 锚点改为「只匹配轴判定」的前缀（语义不变，且不碰新增的 src 项）。
    - M24：cand_ok 多了 & ~cand_foreign ⇒ 锚点跟到当前 RTL。
    - M29：锚点少一个对齐空格（RTL 为 "addr_q <="）。
    - M30：裸 "if (lane_active)" 命中 2 处（:293 注释 + :306 代码）⇒ 改为
    "else if (lane_active)" / "else if (1'b1)"，与旧变异体语义完全一致。
    - M119：push_demo 多了 "| demo_is_off"（P1-2 防挂音）⇒ 锚点跟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
2026-09-29 改动：SEL_DRUM 默认档还原为 0（节拍器）—— 鼓机诊断档 1 曾被 cherry-pick 带进主树，导致默认配置下节拍器事件到不了下游（tb_met_start_top T6 红）；tb_met_start_top 显式 SEL_DRUM(0)、tb_drum_timbre_top 显式 SEL_DRUM(1)（待上板验证）
2026-09-30 上板手册新增 2026-09-30 更新节：S2 改音色键、节拍器改串口 'B'、新增串口 'D' 切鼓机节奏型、四音色与 Test Mode 已实装（旧文说空桩作废）、SEL_DRUM 默认 0=节拍器（听鼓机另编 1）、looper 回放带录制音色、鼓机第4件为嗵鼓、已知未修项、烧录前必查时序
2026-09-30 改动：looper 插值步长引擎三级流水 + ADSR 音色持续比乘法打一拍，收敛时序（待上板验证）
    一、问题（PnR 实测，impl/pnr/Gowin2026_tr_content.html）
    · Numbers of Setup Violated Endpoints = 1702（历史各版均为 0）
    · Actual Fmax = 43.659 MHz（约束 50）、Logic Level = 38
    （历史最好 12 级 / 55.349 MHz，见 7863b40 的 gowin_m0_timing.txt）
    · 最差路径（原文）：
    From g_sound.u_looper/ramp_sc_0_s1/Q
    To g_sound.u_looper/play_upd_inc_o_27_s0/D
    Path Slack -2.905 Data Delay 22.852（周期 20 ns）
    二、根因（两处，由同一批改动引进）
    1) rtl/w3c/looper.v：A2 插值步长把整条链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
    [looper.v]
2026-09-30 新增：鼓机音高包络（阶段 2b）—— 鼓 voice 起音向下扫频，tb_drum_pitch_env 双 DUT 非空洞性判据（待上板验证）
    · rtl/w3b/oscillator_bank.v
    · 新增参数 DRUM_PITCH_ENV_EN(1) / DRUM_SWEEP_SH(10) / DRUM_SWEEP_LSB_SH(8) /
    DRUM_KICK_SWEEP_SH(0) / DRUM_TOM_SWEEP_SH(2) / DRUM_KICK_MAX(10e6) /
    DRUM_TOM_MAX(15e6) / DRUM_CLICK_EN(0)
    · 每 lane 新增 16 位扫频计数器 sweep_q：起音那一拍（与相位复位同一个 if 分支）
    装载深度 = base_inc >> (LSB_SH + 本档 SH)；之后每采样拍
    sweep_q <= sweep_q - (sweep_q >> 10) - 1（指数衰减，τ ≈ 1024 拍 ≈ 21 ms，
    3888 拍精确到 0）
    · 偏移 swee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
    [oscillator_bank.v]
2026-09-30 改动：曲谱 UART 与 looper 同时可用 —— looper 改走 evt_merge 源 C，来源标签加宽到 3 位（待上板验证）
    起因：原 SCORE_UART_ENABLE 让 looper 与曲谱 UART 抢 seq_arb 的 score 口（编译期二选一）
    ⇒ 默认档（0）下灌曲谱不出声。用户要求两个都要。
    - seq_arb：来源标记 NW 2→3 位，SRC_LIVE/SCORE/DEMO 改 3'dN；三源仲裁语义一行未改
    - evt_merge：新增第三个输入 c_*（looper 回放，标签 3'd4），SRC_W 2→3；
    push_n 加到三路；推入改成“紧凑写入”（off_a/off_b/off_c + tail_off，每源一条独立 if）
    ⇒ 覆盖全部 8 种组合；A/B 轮转语义逐位不变（prio_b_r 仍只由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
2026-09-30 改动：note_manager 入口给 env_level_i/env_active_i 打一拍 + 同轴重触发加 ST_RETRIG 流水级（修 25 条同源 setup 违例：逻辑 2.8ns / 布线 20.7ns，32 路写译码 CE 扇出约 4500 端点）（待上板验证）
2026-09-30 改动：本周期合并交付 —— 步进二分基准与步 B/C 工作树 + 时序修复 + 引脚/鼓机/looper 收尾 + 两条诊断判据（全部待上板验证）
    一、已上板验证的关键结论
    · 步 B（基准 9ccf742 ＋ 仅时序修复 478b4ae，= AK_stepB_timing_19bcef2.fs）上板干净：
    ⛔ 无「自检和弦分解版 / 按十几个键才出声 / 按键对应错乱」症状
    · 主树旧 .fs（12:21:35 = AJ 那版）有上述症状 ⇒ 变调 953333e 为首号嫌疑，步 C 已单独出 .fs 定性
    二、本周期内容（37 个提交压缩）
    · 时序修复：note_manager 入口打一拍 + ST_RETRIG 流水级（25 条同源 setup 违例 → 0/0）
    · 引脚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
    [calib_cmd.v, drum_gen.v, evt_merge.v, looper.v, metronome.v, note_manager.v, oscillator_bank.v, seq_arb.v]
2026-09-30 hw(hdmi): 新增 H2/H3 —— 640×480 参数化彩条 + 自写 TMDS 编码器
    为什么改：第三周计划 H2/H3 要求本项目自己的 640×480 彩条输出，以及视频时序参数化。
    H1 只验证了「官方加密 DVI_TX_Top IP + 官方 PLL」这条通路，而加密 IP 给不出 RTL 佐证，
    且赛题要求视觉通路为纯 RTL。
    改前是什么：bringup/ 下只有 H1（hdmi_ref_720p）；rtl/ 中没有任何 HDMI/TMDS 模块；
    constr/top.cst 里没有任何 TMDS 引脚。
    影响什么：新增**隔离工程** bringup/hdmi_640x480/，不接入主工程、不动 96 项回归、不碰已验证的音频链。
    - 纯逻辑层：rtl/video_timing.v（参数化 H_*/V_*，负极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
2026-09-30 revise(第三周计划): H2 的「免 PLL」做不到，更正为必须用 PLL
    原说法：H2「640×480@60 彩条输出（免 PLL：50 ÷ 2 = 25 MHz，误差 0.70%）」。
    更正：**必须用 PLL**。50 MHz 整数分频只能得到 25 MHz 的**像素**时钟；而 TMDS 串行时钟
    必须是 **5 × 像素 = 125 MHz**，50 MHz 无法用整数分频得到 125 MHz。
    原因：TMDS 用 OSER10（10:1 DDR）串行化，其时钟是像素时钟的 5 倍 —— 原措辞只算了像素时钟、
    漏了串行时钟。佐证：H1 的 bringup/hdmi_ref_720p/README.md 早已写明「H2 应重新生成自己的
    精确 25.2/126 MHz PLL」，即 H1 作者已知需要 PLL。按 K-114，PLL 用于外设 /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
2026-09-30 docs(hdmi): 记录方案 B 的构建结果（0 setup / 0 hold，pixel_clk 25.200 MHz）
    为什么改：方案 B（25.2/126 MHz）此前只写了参数与 SDC，标着「未构建」，
    而它隐含的 VCO ≈ 3150 MHz 是已知能跑的两个设计（H1 1100 MHz、A 1000 MHz）的约 3 倍，
    PLL 是否被工具接受一直未知。本轮把它真正构建了一遍。
    改前是什么：SPEC §六 与 README 都写「B 未构建，PLL operating range and Gowin acceptance remain unknown」；
    第三周计划的更正块也写「B 参数与 SDC 已写但未构建」。
    影响什么：B 已构建通过，未知项消除：
    - Gowin 1.9.12.03 接受 MDIV=63 / ODIV0=25 / ODIV1=125（+ SDC 63/25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
2026-09-30 fix(hdmi): DC 平衡判据少算一半（ones-5 应为 2*ones-10）
    为什么改：tb 里那条「输出可观测的 DC 平衡」判据，把每个 10bit 符号的差值算成了
    `ones10 - 5`，而真实差值是 ones − zeros = `2*ones10 - 10` —— 正好差一倍。
    改前是什么：`bal += ones10(sym) - 5`，界仍写 ±8 ⇒ 实际允许到 **±16**，
    判据被悄悄放宽了一倍（虽然仍抓得住 DISPARITY_ZERO，但灵敏度减半）。
    影响什么：改为 `bal += 2*ones10(sym) - 10`，界保持 ±8。
    复跑验证：仿真 `PASS frame=420000 pixels=307200 lines=480 sweep=256`；
    6 条缺陷注入仍全部必红，且 `DISPARITY_ZERO` 现在在 `x=1` 就被抓（此前 `x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
2026-09-30 revise(hdmi): 方案 B 的 PLL VCO 3150 MHz 超出 700–1400 MHz，B 不是可用时钟方案
    原说法：我在 f67ff19 里写「方案 B 已构建通过，原先担心的 fVCO 越界没有发生」。
    更正：**越界确实发生了。** `bitstreams/B_pnr.log` 第 3 行：
    WARN (PA1019) : Invalid VCO frequency
    'FCLKIN*FBDIV_SEL*(MDIV_SEL+MDIV_FRAC_SEL/8)/IDIV_SEL' to 'u_pll'(PLL) ...
    suitable range is from 700MHz to 1400MHz.
    按该告警给出的公式：`50 * 1 * 63 / 1 = 3150 MHz`，远超 1400 MHz 上限。
    对照 A（`50*20 = 1000 MHz`）与 H1（`50*22 = 1100 MHz`）都在范围内，构建日志中**没有** PA1019。
    原因：Gowin 对非法 VCO **只发 WARN、不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
2026-09-30 交付线第一批：修A（calib 水位闸 + autotare 静止守卫）+ K-127（raw 按轴选片）+ 阶段3 + 拒绝原因码 + at_done 门控
    rtl/drivers/calib.sv 水位闸（zero_vld/gain_vld/span_vld）+ 读侧默认值；err 分支不再写 gain_r
    rtl/w3a/calib_autotare.v 静止守卫（帧间变化才拒绝）+ WAIT_CLK 溢出修正 + 'T' 同守卫
    rtl/w3a/calib_span.v span_sent_r2（err 归属本轴）+ rej_why_o（6 条拒绝路径各一个码）
    rtl/top.v K-127（sp_raw_sel 按轴选片）+ cal_err_any/cal_busy_all + at_done 门控 'S'
    tb/w3a/* 两个新判据 tb（span_err / still_guard）+ 两个既有 tb 更新
    sim/pnr_run.ps1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
    [calib.sv, calib_autotare.v, calib_span.v, tb_calib_autotare.sv, tb_calib_span_err.sv, tb_calib_still_guard.sv, tb_uart_calib_chain.sv]
2026-09-30 ESP32 线：放水打通 + 三个真缺陷修复 + 500k 对齐 + 验收工具
    放水修复（本轮从"永不发数据"到"200 帧全放完"）：
    pool.c delta_us_to_ticks 夹紧把长时长截短 => 放水条件数学上不可达
    pool.c s_due_tick_last 哨兵排在钳位之后 => 首轮真值被打残并固化 => 永久追赶
    send_frames_ble.py 假曲谱注入 50 个伪造 kind=2 换速 => 固件反复重锚时间基准
    配置对齐：
    BLE_BAUD 1000000 -> 500000（FPGA 侧 09-24 已降，ESP32 侧未跟上 => 会静默乱码）
    按键 GPIO0 -> GPIO6（GPIO0 是 strapping 脚，复位时按住会进下载模式）
    新增起播触发三种模式 SERIAL/GPIO/NONE（pool_start 原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
    [ble_config.h, ble_main.c]
2026-09-30 hw(hdmi): 加 V13 心跳 LED（活体见证 + PLL 锁定指示）
    为什么改：H2 首次上板时屏幕全黑，而**无法区分**三种完全不同的原因：
    ① 码流根本没烧进去 / ② 烧进去了但 PLL 没锁 / ③ PLL 锁了但 TMDS 或显示器有问题。
    需要一个不依赖显示器、不依赖示波器的板级活体见证。
    改前是什么：hdmi_top 没有任何状态输出脚，上板后唯一的反馈就是 HDMI 屏幕。
    影响什么：新增输出 `led_hb`，接到 Console 的 `CFG_LED` 绿灯 = `SYS_ACT` = **`V13`**
    （与主工程 `constr/top.cst` 的 `led_heartbeat`、`bringup/dac_tone` 的心跳脚同一个 ball，
    也是本项目上板手册一贯的判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
2026-09-30 hw(hdmi): H1 官方 720p 参考也加 V13 心跳 LED（做同灯的对照实验）
    为什么改：H2 首次上板屏幕全黑。给自研设计加心跳后读到「~1 Hz」，
    证明「码流在跑 + PLL 已锁」，问题被定位到 PLL 之后（TMDS 编码 / 引脚 / 显示器）。
    但下一步需要一块「同灯、不同 TMDS 通路」的对照：官方加密 DVI_TX_Top IP + 官方 PLL 参数。
    若 H1 也黑屏，则物理层（引脚/连接器/HPD/显示器）有问题，自研设计无辜；
    若 H1 出图，则责任在自研的 640×480 通路。
    改前是什么：hdmi_ref_top 只有 hdmi_en 输出，没有任何状态指示 ⇒
    它黑屏时无法区分「没配置」与「配置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
    [hdmi_ref_top.v]
2026-09-30 fix(hdmi): TMDS 输出改 ELVDS_OBUF + IO_TYPE=LVCMOS33D（LVDS25 是黑屏头号嫌疑）
    为什么改：H2 首次上板屏幕全黑（无任何 OSD 提示），但心跳 LED 读到 ~1 Hz，
    证明「码流在跑 + 50 MHz 时钟正常 + PLL 已锁」。于是问题被定位到 PLL 之后的
    TMDS 输出级。查证 Tang Console 上**实测跑通**的第三方实现
    （nand2mario/tangcore，Console 官方致谢作者，其复古核心即在该板运行）的
    src/boards/console.cst：TMDS 四对差分全部写 **IO_TYPE=LVCMOS33D**（3.3 V 差分），
    且**不例化任何差分输出原语**。
    改前是什么：我们沿用 H1 的写法——cst 不写 IO_TYPE，RTL 里用 TLVDS_OBUF
    （真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
    [tmds_serializer.v]
2026-09-30 fix(hdmi): TMDS 控制码表 2'b01/2'b10 写反 —— 上板全黑的真根因
    原说法：编码器 case({c1,c0}) 里 (c1,c0)=2'b01 → 0101010100、(c1,c0)=2'b10 → 0010101011；
    SPEC §四、tb 的 token() 参照表、解码模型 tb/tmds_decoder.sv 三处抄的是同一张表。
    更正：(c1,c0)=2'b01（c0=HSYNC=1, c1=VSYNC=0）应为 0010101011；
    (c1,c0)=2'b10 应为 0101010100。编码器 / tb 参照表 / 解码模型三处一并改正。
    原因（上板实测链）：F（官方加密 IP，720p）与 I（官方 IP + 640×480@25.000 MHz + LVDS25）
    都能出彩条 ⇒ 引脚、连接器、线材、显示器、IO 标准全部无罪；而我们的设计一直全黑。
    逐项排除串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
    [tmds_encoder.v, tmds_serializer.v]
2026-09-30 docs(hdmi): 记录 H2 上板验收通过（640×480 彩条实测出图）
    2026-09-30 实测：把 bitstreams/J_TOKENFIX_led.fs 以 SRAM Program 烧入
    Tang Console 60K（GW5AT-LV60PG484AC1/I0），接 HDMI 显示器后**出八色彩条**，
    V13 心跳 LED ~1 Hz（50 MHz 时钟与 PLL 锁定正常）。
    这达成的是 H2 的**原始验收判据「屏幕出彩条」**，而且是**本项目自己写的 RTL**：
    自研 TMDS 8b/10b 编码器 + 4× OSER10 + 自研 PLLA（MDIV=20/ODIV0=8/ODIV1=40 →
    25/125 MHz），不是加密 IP。
    同一次上板顺带证明：TMDS 引脚分配（源自官方 NEO_DOCK.cst，并与
    nand2mario/tangcore src/boards/console.cst 独立核对一致）、LVDS25 输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
2026-09-30 docs(hdmi): 归档 H2 上板调试记录与对照实验脚本
    为什么改：H2 从"全黑"到"出彩条"的排查链（8 步假设-实验-判定）与三条对照配方
    （F 官方 720p、I 官方 IP+640×480、E 分数分频）此前只存在于会话与临时工作区，
    一旦丢失，下次遇到"有信号但出不了图"会重走一遍。
    改前是什么：`bringup/hdmi_640x480/` 只有交付源码与 README/SPEC，
    没有"怎么排查"的记录，也没有对照码流的构建配方。
    影响什么：新增
    - `上板调试记录-20260930.md`：症状、8 步排查链（每步的假设/证据/判定）、根因、
    三条对照配方、6 条教训（含"协议常量不能只靠往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
2026-09-30 ESP32 线：反向通路打通 + 上行蓄水/放水缓冲 + 一键端到端验收
    【反向通路（FPGA -> ESP32 -> BLE -> PC）—— 首次跑通】
    🔴 gatts_if 传错：notify 传了 ESP_GATT_IF_NONE(=0xFF) 被当成 conn_id=255
    日志铁证 E BT_APPL: Unknown connection ID: 255 fail sending notification
    => 改成 s_gatts_if；实测 21 字节原样回传
    🔴 BLE_TX_GAP_MS 延时陷阱：pdMS_TO_TICKS(2) 在 HZ=100 下塌成 0 => 忙等
    改走 BLE_DELAY_TICKS_AT_LEAST_1（该通路一直没跑通，所以这个延时从未被执行过）
    🔴 CCCD 订阅竞态：原来把"已连接"当"可以发了" => 连接一建立就放水，
    而客户端还没订阅 =>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
    [ble_config.h, ble_main.c]
2026-09-30 ESP32 线：CMD 命令集 + 上行蓄水/放水缓冲 + 一键验收 + 用户裁定落地
    【CMD 0xABF3 从"废的"变成可用】
    原缺陷：判据写成 `h == recv || h == cmd` => CMD 口被当曲谱数据吃掉
    现有命令：0x01 清池 · 0x02 上报状态(写 0xABF4) · 0x03 起播 · 0x04 停止
    未知命令计数+日志，不静默吞
    ⚠️ 起播/停止是用户 Q1 裁定"走模式B"之后才加的一一裁定前刻意不做
    【修 0xABF4(STAT) 读回永远为空】
    根因：属性用 ESP_GATT_AUTO_RSP + length=0 => 自动响应回的是声明长度 0
    修法：改 ESP_GATT_RSP_BY_APP，READ_EVT 里自己填长度
    ⭐ 实测读回 b'pool=0/18204 sent=0 ovf=0|ring=0 u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
2026-09-30 ESP32 线：安全关闭板载 WS2812 + PC 端 MIDI 回传工具链
    【安全优先：关闭板载 WS2812 指示灯（用户："先把灯关了，安全第一"）】
    ⭐ 用户的关键提醒：WS2812 有【锁存】
    => 它把最后一次收到的 24 位值锁住，即使固件停了 / 重启都会一直亮
    => "不用它" != "它是灭的"
    => 两层做法（缺一不可）：
    ① WS2812_ENABLE = 0 不再点亮
    ② WS2812_CLEAR_ON_BOOT = 1 开机发一帧全 0，清掉遗留锁存
    🔴 修两个"关不干净"的真 bug：
    · ws2812.c 编译守卫写成 #if WS2812_ENABLE
    => 一关指示灯，"清锁存"整段不编译 => 灯永远停在旧颜色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
    [ble_config.h, ble_main.c]
2026-10-01 周期交付（2026-10-01）：量纲返工修复 4 条上板回归 + T3 复核 + Verilator 评估
    修复（本轮最重要）：
    🔴 上板实测 4 条回归 —— 力度跟随消失 / 总音量变小 / 触发更不灵敏 / 尾音变短
    ⭐ 根因（二分定位）：BATCH 2 与 BATCH 4 的常量是按【跑过 span 的 4095 档】定的，
    而板上一直是【只 tare 的 ~744 档】⇒ 一组量纲错，四处症状
    ✅ 修复：EVT_TRIG_TH 205->64 · EVT_REL_TH 102->32 · POS_FULL 解耦到 TRAVEL_TARE(744) ·
    vel 斜率 48->263 · 加 2 条锚定自检 · tb 镜像同步回滚
    ⭐ 用户已上板确认：4 条全部消失，且键 14/15 与"第一下就响"未丢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
    [adc_farm.sv, calib_autotare.v, note_manager.v, tb_calib_span_err.sv, tb_calib_still_guard.sv, tb_e2e_key_to_sound.sv]
2026-10-01 周期交付（2026-10-01 晚）：键盘打鼓模式 + 鼓音高拉开 + ESP32 回函 + 任务清单
    新增功能：
    ⭐ 键盘打鼓模式（串口 'K' ⇒ 回 'k'）—— 磁轴键盘变鼓垫
    映射依据用户的鼓垫图（files/10-硬件/鼓垫.drawio.svg）：16 键 = 2 板 × 8 通道，
    四件乐器各占 2×2 象限 ⇒ 恰好归约为两位切片 axis[3:2]
    axis 0-3 嗵鼓 · 4-7 底鼓 · 8-11 军鼓 · 12-15 踩镲
    实现只在源 A 装配处加三个 mux：换 phase_inc、标 src=SRC_AUX(3)（⇒ 进保留池 +
    perc 包络）、固定 timbre=DRUM_TIMBRE。note_manager / oscillator_bank /
    perc_env_bank 一行都没改。
    上板反馈后的两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
    [calib_cmd.v, drum_gen.v, oscillator_bank.v]
2026-10-01 hw(hdmi): H4 上板验收通过 —— 1920×1200@60（OSER10 768.75MHz / 1.5375Gb/s 实测可用）
    原说法：第三周计划给 H4 的时钟是 `50 × 77 / 25 = 154 MHz`（VCO = 50×77 = 3850 MHz，违规）；
    且 H4 所需速率能否实现未知——静态时序里 serial 域【没有可计算 Fmax 的路径】，
    "0 违例"是空真，器件额定速率与板级能力此前都没有依据。
    更正/实现：
    - PLL 合法化。硬约束：VCO = 50×(MDIV_SEL + MDIV_FRAC_SEL/8) ∈ [700,1400] MHz，且 serial = 5×pixel
    ⇒ 只能取 ODIV0_SEL=1、ODIV1_SEL=5；取 MDIV_SEL=15 / MDIV_FRAC_SEL=3
    ⇒ VCO(serial) 768.75 MHz、pixel 153.75 MHz（对 154.000 偏 −0.162%），帧率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
2026-10-01 周期交付（2026-10-01 夜）：底鼓/嗵鼓二次拉开 + 键盘打鼓全套（含队友 H4 HDMI 之上）
    ⭐ 本周期在【队友 b41adf8（H4 HDMI 上板验收通过）之上】变基后合成 1 个提交，
    ⛔ 未覆盖队友任何改动（⭐ 两边文件无交集，⭐ 已逐文件核对）。
    鼓的区分度（用户两轮上板反馈）：
    第一轮："4 个鼓听不太出来区分度"
    根因：oscillator_bank.v:699-701 —— 凡判成鼓的 voice 一律取噪声表 ⇒ 音色与乐器无关，
    只剩播放速率与扫频在区分。原军鼓(192Hz)与嗵鼓(144Hz)仅差 4.2 个半音。
    改为 14.3 / 19 / 32 个半音（军鼓 192→480Hz 是关键）。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
    [drum_gen.v, oscillator_bank.v]
2026-10-01 ESP32线：串口屏HMI全链路修复 + 19工具/317项离线自检 + 上行帧解析（含68B表同步）
    串口屏 HMI（7）：验收通过 · 屏→ESP32 诊断 · hmi.tx 发送侧计数 · 修 4 个死功能
    （播完/就绪/待机/曲名 g0）+ 2 个 STAT 真 bug（计数跨曲累加、显示落后一拍）·
    CMD 0x20/0x21/0x22 · 上屏演示工具 + 起播提前量实测
    自检体系（5）：selftest_all.py 一条命令枚举 · 6 个验收工具 + rec_upstream 补
    --selftest · regress_live.py 活体回归 · C115 第二层修法（STAT 陈旧可判定）·
    全工具 + 全固件回归复跑
    上行帧/协议（3）：0xABF4(STAT) 扩六组 + 修 append→replace 真 bug ·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
    [ble_main.c]
2026-10-01 T2 起始音(BA) + 器件修正：PnR 改用实物器件 AC1/I0，真实 Fmax 50.137 MHz
    本批 11 个本地提交压成 1 个（远端基点 4bb6353）。
    【功能 / 证据】
    - T2 起始音（BA）：把长期悬空的 ui_base_semi 接进 note_manager；tb_base_semi 10/10；
    全量回归串行 通过 111 / 共 111
    - P2-1/P2-2：top.v 的 4 条 $display 自检改成【能红】断言 + 补 POS_FULL 集成值判据
    - 文档：T2 实施方案 / T3 变调与推子设计定稿 / 下一步任务计划 v2 / 计划推进表 / 上板卡 24·25
    【器件修正 —— 本批最关键】
    - K-170：Gowin 读的是 <Device> 元素的【文本】(器件 id)，pn= 属性只是标签、不决定器件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
    [note_manager.v, tb_base_semi.sv, tb_integration_consts.sv]
2026-10-01 hw(hdmi): H5 波形显示接入主设计（旁接 master_mix）—— 上板验证通过
    实现：
    - rtl/hdmi/waveform_scope.v：24 位有符号样本 → 640×480 波形渲染。1024 深度环形历史，
    消隐时快照最近 640 点，y = clamp(240 - (sample >>> 14), 0, 479)，逐列画相邻点之间的
    竖线；亮绿波形 / 暗灰基线 / 黑底。独立帧 RAM 避免扫描期间被新样本覆盖造成撕裂。
    - rtl/hdmi/hdmi_scope.v：640×480@60（25 / 125 MHz）显示通路封装，复用已验证的
    video_timing / tmds_encoder / tmds_serializer / hdmi_clk。
    - rtl/top.v：只做加法 —— 增加 HDMI 输出端口与 hdmi_scope 例化，被动旁接 master_mix 的
    vali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
2026-10-02 perf(timing): 两轮队列减宽（seq_arb / evt_merge）+ 口径统一与符号锚点
    时序（本机实测，GW5AT-LV60PG484 C1/I0）：
    - A1：seq_arb 队列控制按 DEPTH 参数化（DEPTH=6 ⇒ 3/3/4 位）⇒ Fmax 50.137 → 52.798 MHz
    - evt_merge 同族减宽（DEPTH=6 ⇒ 3/3/4/2 位）⇒ Fmax 52.798 → 58.581 MHz，该族 23 条 → 0（退出 Top25）
    - 每项都过 8 条判据：单元 tb（含非默认 DEPTH 位宽契约，旧 RTL 必红）· 逐拍差分（5 种 DEPTH × 20000 拍，0 不一致）
    · 只综合门 ERROR=0 · 网表位宽证据 · 全量回归 112/112（验收口径 108/112）· PnR 0 setup/0 hold · 逐路径族对比
    - 变异锚点 M64~M68 全部 RED(caught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
    [axis_map.v, calib.sv, calib_cmd.v, drum_gen.v, event_extract.v, evt_merge.v, evt_merge_ref.v, metronome.v]
2026-10-02 fix(timing): 合并后 clk_sys 21 条 setup 违例 → 0（回传锥定向区域约束）+ 交给时序优化线的收敛请求
    【问题】main(H5) 与队友分支 timing/evt_merge-20261002 合并后，同一份源码连续两次构建
    结果逐位一致：clk_sys Actual Fmax 44.757 MHz、setup 违例 21、hold 0。最差路径
    g_sound.u_calib_span/reject_o_s0/Q → u_tx_fifo/mem_mem_RAMREG_*_G[1]_s0/D，slack −2.343，
    数据路径 22.080 ns 中【布线 20.303 ns ≈ 92%、组合逻辑仅 1.447 ns、时钟偏斜 0.000 ns】，
    该网在芯片上反复横跨（R58C3 → R52C146 → R50C38 → R50C146 → R57C22，四段约 18.331 ns）。
    【排除项】逐文件比对：合并后的 RT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
2026-10-02 fix(timing): clk_sys 50.040 → 53.425 MHz（+6.85%）—— note_manager 扫描预译码 + test_mode_ctrl 译码去共享【代修】
    【为什么是代修】本改动落在队友 Hokuu 的音频 RTL（rtl/w3b/note_manager.v、rtl/w3b/test_mode_ctrl.v）。
    他当前无法操作，DSH 按其批准的方案代修。改动全部有独立证据，便于他回来看：
    - 逐拍差分 0 差异（周期行为不变）
    - 红-绿证据（故意错误版本必红）
    - 网表证据 + 全量回归 + PnR 时序
    【背景】含 H5 的完整树在器件 C1/I0 上原本 clk_sys = 50.040 MHz（余量 +0.08%），
    低于项目门槛 51.5 MHz / 3%。12 条最差 setup 路径里 10 条是同一个锥：
    g_so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
    [note_manager.v, summarize_regression.py]
2026-10-02 docs(timing): 记录时序修复 + H5 的上板功能验证（都正常）
    上板（2026-10-02）：码流 M_timing53p425_h5.fs（SHA-256 DCF66548…E4BF9A，19,190,855 B，
    构建于 18:59:49，器件 GW5AT-LV60PG484AC1/I0）以 SRAM Program 烧入 Tang Console 60K 后：
    V13 心跳 ~1 Hz ✅、音频与上一版一致 ✅、HDMI 黑底绿波形随演奏变化/静音回中心线 ✅
    —— 用户确认「都正常」。
    对应静态时序（同一份源码）：clk_sys 53.425 MHz（+6.85%，过 51.5 MHz / 3% 门槛）、
    pixel_clk 136.857 MHz、setup/hold 违例 0/0、PA1019/ERROR = 0、最差 hold slack +0.192 ns；
    全量回归（最终源码，串行）通过 113 / 共 113，0 失败/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
2026-10-02 docs(plan): 更正第三周计划 v1/v2 里 Fmax 数字的器件档位前提（AC2/I1 ≠ 实物 AC1/I0）
    【问题】第三周计划 v1 的「一、当前状态（2026-09-29 实测）」写着
    「PnR | 0 setup / 0 hold；Actual Fmax 55.349 MHz（余量 +10.7%）」；
    v2 实测修正版把左列改成 53.821（+7.64%）。但按队友的 K-170/K-171：
    2026-10-01 之前所有构建的 `<Device>` 元素文本都是 `gw5at60b-003`（**AC2/I1**，基石板速度级），
    而实物是 **AC1/I0**（Tang Console 60K）⇒ **55.349 与 53.821 都是 AC2/I1 的数字，不代表实物板卡**。
    Gowin 读的是 `<Device>` 的**文本**（器件 id），`pn=` 属性只是标签、不决定器件。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
2026-10-03 timing/converge-h5-20261003：BATCH5 音高判据 + T3 参数门控 + 串口 F/G/H/J + 推子档位状态机(含 A'/防抖动) + 20 根引脚 + 硬件交接
    【P1 T3 变调参数门控】note_manager 加 parameter T3_EN=0：变调核心被 generate 门控排除出综合 ⇒ 综合/Fmax/slack 逐字回到无 T3 基线（37026/15698/5 · 53.425/1.282/0.128）、PnR 出位流、PR0004=0；T3_EN=1 一键回到 T3 语义。二分已定位根因：T3 成本 +1961 LUT = A(数组+写译码 82) + B(32 lane 输出 mux 1025，元凶) + C(读 mux+乘法器+表 854)，三条减重路均实测布不通 ⇒ 需从别处腾资源（P4）。
    【P2 串口 F/G/H/J】calib_cmd 扩 4 条（F 降1半音/G 升1半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
    [device.cfg]
2026-10-03 docs(h5): 收口记录 —— 显示修复离线有效但代价是时序，交付停在 53.425 MHz 达标版
    【收口状态】源码停在 d449504（= 标签 timing-53p425-h5-20261002，已推远端）：
    clk_sys 53.425 MHz、setup/hold/recovery/removal 全 0、过 51.5 MHz 门槛；
    ⚠️ 带 H5 "两条线/残影"显示缺陷。H5 触发显示修复不在树上，完整保存在
    evidence/h5/experiment-tree-20261003/（补丁 + 7 个文件），可随时 git apply 恢复。
    【用户评估】"一根线效果不是很好" ⇒ 不并入交付版本。
    【本轮做了什么（全部实测，见文档附录 A–D）】
    · H5 显示"两条线"根因定位：离线逐像素 dump 证明 RTL 一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
    [test_mode_n32.csv]
2026-10-03 docs(h5): 对照实验闭环 —— 证明"一根线"显示修复就是时序变差的原因；并记录 set_option 持久化陷阱
    【结论】同样的默认 PnR 选项下：
    · 无显示修复（d449504，2026-10-03 20:09 干净重建）= clk_sys 53.425 MHz / 0-0
    ⇒ 与 10-02 18:59 那次【逐字节相同】（码流仅 9 字节不同，偏移 635–653 正是时间戳头）
    · 加了一根线修复（10-03 13:43 重建）= clk_sys 50.527 MHz / 0-0
    ⇒ 显示修复使 clk_sys 下降 2.898 MHz（−5.4%），附录 D.3 的保留意见解除。
    ⇒ 同时证明 PnR 对本工程是确定性的（同源 + 同选项 ⇒ 完全相同的产物）。
    【流程陷阱（重要）】set_option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
2026-10-03 docs(h5): 合并队友 converge-h5 分支并验证其时序（独立复现 SETUP#1 0.850）
    【合并】origin/timing/converge-h5-20261003（375d176，基点 7946604）合入 main。
    冲突仅 9 个 sim/evidence/* 日志（取他的，均为可再生产物）；RTL/约束零冲突。
    关键校验：H5 接入与 h5_ret 保留、他的 T3_EN 门控与 fader_gear.v 在树、
    top.cst 62 条 IO_LOC、top.sdc 未被污染、build_cli.tcl 与他一致。
    【独立复现】在全新 impl/（先删，避免增量状态与配置污染）用默认选项
    （新 cmd.do: -place_option 0 / -route_option 0）构建合并树：
    Part Number GW5AT-LV60PG484AC1/I0
    setup 0 / hold 0
    clk_sys 50.000 -> 52.21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
2026-10-03 feat(c/guide_lamp): 音符事件→灯位指引映射层 (P1) + tb + 变异体 M137~M139
    丙线 P1 核心：把 play_seq 的音符事件流(axis字段 bit22..19)解码成
    16位 one-hot guide_key 指引位图，填补 led_data 的 guide_key_i 输入源缺口。
    - 纯新增文件，不改 play_seq/note_manager/top.v
    - 判据可红(16条) + 非空洞性(轴号0..15满射)
    - 变异体 M137~M139 已验证可被抓到
2026-10-03 丙 P4: 效果器延迟预研（delay 环形缓冲 BSRAM 预算 + 挂载点 + 选型路线）
2026-10-03 docs(h5): 路线一① 试做并回退 —— 结构成功但全局 Fmax 反降；保留逐拍差分测试台
    【试做了什么（codex 路线一①）】rtl/top.v：把 ADSR 的 gate/velocity/retrig 选择
    从"全局 tm_enable_r（扇出 769）组合选择"改为"每声部本地 2 位选择器 tm_sel_r"
    （0=普通 / 1=测试声部 / 2=测试模式但非测试声部），并在**与权威状态同一个上升沿**
    写入下一状态的分类（⛔ 不是晚一拍）。
    【前置验证（codex 硬要求，已通过）】新增 tb/w3b/tb_top_test_mode_pipe.sv：
    逐**系统时钟沿**差分"旧选择 vs 新选择"，**6229 拍 0 差异**，且红检有效
    （故意晚一拍的变体被抓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
    [test_mode_n32.csv, top_sound_samples.csv]
2026-10-03 docs(h5): 候选三第 1 步（ADSR 算术共享）试做并回退；记录"增量优化空间已用尽"的最终结论
    【试做】rtl/w3b/adsr.v：把分散在带优先级 case 分支里的加减（env+attack / env-decay /
    env-release）提到 case 之外无条件各算一次，强制一份加法器 + 一份减法器
    （dn_step_sel 用 releasing 做步长 mux）。语义逐位不变。
    【前置验证】tb_adsr / tb_timbre_adsr / tb_envelope_bank / tb_timbre_event_path 四个全绿
    （它们检查包络的绝对期望值、四音色配方与边界，强于差分）。
    【构建结果（全新 impl + 默认选项）】setup 0 / hold 0；
    clk_sys 52.219 -> 50.035 MHz（-2.184）；
    Logic 5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
2026-10-03 docs(h5): 继续提升时序的完整实验记录（6 次实验全部按判据回退）+ 关键发现"降 CLS 方向正确"
    【实验总表（全新 impl + 默认选项，全部实测）】
    基线（合并树） Logic 50680 CLS 26886 clk_sys 52.219 ✅ 交付
    1 候选一 place=2/route=1 — — 3906 条未布线 ❌ 布不通
    2 候选一 place=1/route=1 — — 103 条未布线 ❌ 布不通
    3 路线一① 控制预译码 目标锥消失✅ 26860 50.641 ⇒ 回退
    4 候选三-1 ADSR 算术共享 Logic −720 26996 ↑ 50.035 ⇒ 回退
    5 候选三-2 力度斜坡合并 Logi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
2026-10-04 feat(timing): 阶段 0 余量约束 + 阶段 1 TEST_MODE_EN 双码流（按 codex 评审计划执行）
    【背景】codex 只读评审 margin-roadmap-review-20261004（expert/astra/xhigh）给出 6 阶段计划。
    本提交完成阶段 0 与阶段 1，两次完整构建均已实测。
    【阶段 0：margin SDC（不动 RTL）】constr/top.sdc 末尾加两条 set_max_delay：
    · clk_sys → clk_sys : 19.417 ns（≈51.5 MHz 余量预算；精确 19.4174757 ⇒ 略紧）
    · clk_sys → u_hdmi/u_scope/gray_launch_*_s0 + full_launch_s0 : 10.000 ns
    （钉住 negedge sample_clk 的半周期预算，防止被上面那条意外放宽）
    ⛔ 未使用 set_clock_groups -asynchronous（那会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
2026-10-04 docs(timing): 阶段 2（鼓扫频 per-lane→per-voice）前置检查通过 + 待执行设计规格
    【前置检查（codex 要求，已完成）】
    综合网表 impl/gwsynthesis/Gowin2026.vg 里 sweep_q 触发器实例 = 1024 个
    （64 lane × 16 位）⇒ **综合器没有自动合并** ⇒ 阶段 2 有真实收益：
    可省 512 FF（1024→512）+ 一半分类比较器/桶形移位/衰减算术。
    落点：rtl/w3b/oscillator_bank.v:290 gen_lane 循环（VOICE_IDX=g/2、OSC_IDX=g%2）。
    【等价性论证（已推导）】
    同 voice 两 lane 的 base_inc（L339-340，不含 OSC_IDX）、is_kick/is_tom（L386-388）、
    sweep_load（L394-403）、sweep_dec（L420-421）**完全相同**；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
2026-10-04 perf(timing): 阶段 2 鼓扫频 per-lane→per-voice 共享 —— clk_sys 51.551 → 53.652 MHz（首次真正超过基线）
    【前置检查（codex 要求）】综合网表 sweep_q 触发器 = 1024 个（64 lane × 16 位）
    ⇒ 综合器没有自动合并 ⇒ 有真实收益。落点 rtl/w3b/oscillator_bank.v:290 gen_lane。
    【实现】新增 gen_voice_sweep 生成块（按 voice 共享扫频状态与分类/装载/衰减算术），
    per-lane 的 sweep_off 改为读共享值 ⇒ 原 per-lane 的 sweep_q/sweep_dec/sweep_load/鼓分类
    成为死逻辑，由综合器剪除。
    等价性：同 voice 两 lane 的 base_inc（不含 OSC_IDX）/鼓分类/装载值/衰减逐位相同；
    reload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
    [oscillator_bank.v]
2026-10-04 perf(timing): 55 MHz 余量预算挑战通过 —— clk_sys 53.652 → 56.399 MHz（+9.5% 余量）
    【改动】constr/top.sdc 的余量预算 19.417 → 18.181 ns（≈55 MHz，精确 18.1818182 ⇒ 略松）
    【实测（全新 impl + 默认选项 + TEST_MODE_EN=0 + 阶段 2 共享）】
    Part Number GW5AT-LV60PG484AC1/I0；setup 0 / hold 0
    clk_sys 50.000 → **56.399 MHz**（上一版 53.652；合并树基线 52.219；老基线 53.425）
    最差 setup slack = **+0.450 ns**（按 18.181 ns = 55 MHz 预算）⇒ **55 MHz 预算达标**
    资源：Logic 46283 / CLS 25725（86%）/ Register 15148（与 19.417 版基本一致）
    新最差路径：note_manager/gate_r_24 → scan_cnt_3/CE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
2026-10-04 feat(timing): 双码流配齐 —— 诊断版 TEST_MODE_EN=1 也通过 55 MHz 预算（55.198 MHz）
    【实测（全新 impl + 默认选项 + 18.181 ns 预算）】
    正式版 TEST_MODE_EN=0：clk_sys 56.399 MHz、55 MHz 预算 slack +0.450、CLS 25725(86%)
    诊断版 TEST_MODE_EN=1：clk_sys **55.198 MHz**、55 MHz 预算 slack **+0.065**、
    setup 0 / hold 0、Logic 48823、CLS 26446(89%)
    ⇒ 两个码流都独立通过 51.5 门槛，且都通过 55 MHz 预算。
    诊断版最差路径：tdm_render_mixer/cnt_4 → prod_c_0（+0.065）、
    g_test_mode.tm_n_code_q → ADSR（+0.074，Test Mode 锥回来了但不主导）
    【测试】诊断配置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
2026-10-04 feat(timing): 正式版码流重建交付（56.399 MHz 逐项复现）+ 双码流归档
    【正式版重建（TEST_MODE_EN=0 + 18.181 ns 预算 + 全新 impl/）】
    clk_sys 50.000 → **56.399 MHz**（与上一次正式版逐项一致 ⇒ PnR 确定性再次确认）
    55 MHz 预算 slack +0.450 ns；Logic 46283 / Register 15148 / CLS 25725(86%)
    码流 18,902,023 B
    【交付】两个码流已放到 Desktop\学习\hdmi_640x480\bitstreams\：
    P_prod_TESTMODE0_56p399.fs（正式版，上板交付）
    Q_diag_TESTMODE1_55p198.fs（诊断版，保留完整 Test Mode）
    evidence/h5/testmode1-18p181-55p198/README.md 已追加交付更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
2026-10-04 docs(h5): H5 显示修复按用户决定结案（不需要）；记录时序攻坚最终成果与一个独立 CDC 遗留项
    【H5 结案】用户 2026-10-04 明确「现在 h5 不需要显示修复」⇒ 显示侧工作全部关闭：
    · 不并入显示修复；源码与离线验证证据完整保留在 evidence/h5/{experiment-tree-20261003,
    triggered-scope-20261002}/，随时可 git apply 恢复
    · 当前树确认不含任何 H5 改动（waveform_scope 无触发窗口、tmds_serializer 无 serial 同步器、
    top.sdc 无 get_regs 例外）
    · 两条与显示无关的回归测试保留：tb_top_test_mode_pipe.sv（测试模式选择逐拍等价）、
    tb_note_manager_vel_ram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
2026-10-04 docs(h5): 上板验证通过 —— 交付闭环（56.399 MHz 正式版 + 55.198 MHz 诊断版）
    用户 2026-10-04 实测：「上板了，测试没问题」⇒ 整条链闭环：
    源码 → 约束 → 综合 → PnR → 时序验收 → 码流 → **上板功能验证** 全部通过。
    【最终交付】
    正式版 P_prod_TESTMODE0_56p399.fs：56.399 MHz / setup 0 / hold 0 / CLS 25725(86%) / 已上板 ✅
    诊断版 Q_diag_TESTMODE1_55p198.fs：55.198 MHz / 0-0 / CLS 26446(89%) / 保留完整 Test Mode
    相对合并树基线：clk_sys +8.0%、余量 vs 51.5 门槛 +1.40%→+9.51%、相对 50 MHz +4.44%→+12.8%
    【附录 I 内容】验收对照表、最终交付清单、7 条可复用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
2026-10-04 docs(h5): 确认上板的是正式版（56.399 MHz / TEST_MODE_EN=0）；记录下一步为继续降 CLS
2026-10-04 docs(timing): 下一轮降 CLS 的靶子分析与实施任务规格（xats 派发受阻，规格先落仓）
2026-10-04 revert(timing): 回退 note_manager 降 CLS 尝试（CLS 反增 +87、clk_sys 56.399→55.054）；归档 codex 过程物与两个未实施候选
    [top_sound_samples.csv]
2026-10-04 timing/converge-h5-20261003：逻辑优化（ADSR 共享 + P5-② + T3 变调 + 灯带指示层）＋ 合并队友时序线
    ⭐ 本周期一个提交（⛔ 不是把中间提交原样推上去）· ⭐ 基线 = `origin/main` = 7b1182c
    ⭐ 备份：tag `pre-squash/2026-10-04`（= 压缩前的 66d6b07）＋ bundle
    `C:\Users\hokuu\Desktop\_tmp\FPGA2026-pre-push-2026-10-04.bundle`（77 MB · 173 refs 已 verify）
    【⭐ 成果：功能变多了，资源反而更小、时序更高】
    T_Lut CLS Fmax 全量回归
    本周期开始（H5 收口） 37075 ~90% 53.425 118/118
    ⭐ 现在（含队友的） 27099 78% 56.351 124/124
    ⇒ ⭐ T_Lu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
    [top_sound_samples.csv]
2026-10-04 fix(merge): 补回被本线早先删除的 26 个 evidence/h5 文件（⭐ 队友的 H5 实验证据）—— 使本线成为 main 的超集，快进/合并都不会删掉队友的东西
2026-10-04 chore: 归档回退后的重建日志（恢复 56.399 交付状态）
2026-10-04 docs(timing): 记录阶段 2（扫频共享）在合并甲分支时被覆盖，附恢复方法与归档位置
2026-10-04 docs(timing): 更正判断——阶段 2 是被甲的 P5-② 超集取代（非丢失），无需恢复；开始独立复现合并版
2026-10-04 verify(timing): 独立复现合并版 56.351 MHz（与甲报告逐项一致）+ 交付 R_merged_56p351.fs
2026-10-04 docs: 上板操作指南（合并版 R_merged_56p351.fs）—— 引脚/参数/命令均对着源码逐条核对
2026-10-04 docs(timing): RIGHT_ADC_ENABLE=1（右手板联调档）时序不达标（46.613 MHz / 1630 违例）—— 记录结论并回退参数到 0
2026-10-04 docs: 上板指南补右手板 A 章节（甲文档未覆盖）—— 通道映射/接线/RIGHT_ADC_ENABLE 编译期限制/46.613 MHz 时序障碍/4 个码流对照
2026-10-05 docs(hw): 右手板拨弦诊断收尾 —— 实测证明极性正确、UP 不触发、DOWN 响应前推；结论=板子/接线问题，附硬件侧最小复现步骤与 RTL 勿改清单
2026-10-05 exp(audio): 限幅前裕量 -6dB -> -12dB（修法1）—— 针对 3+复音 x 高持续比音色(0/3) 的软限幅爆破音；clk_sys 55.143 / 0-0；待上板验证
2026-10-05 feat(T5): 延音踏板语义 ＋ 合并队友（限幅裕量/右手板诊断）
    ⭐ 基线 = `origin/main` = b72e3bf（⭐ 已并进来）· ⭐ 本周期压成 1 个提交
    ⭐ 备份：tag `pre-push-t5/2026-10-04` ＋ bundle `…\_tmp\FPGA2026-pre-push-t5-2026-10-04.bundle`
    【① T5 延音踏板语义（第三周计划 v1 §3.1 任务表 T5）】
    ⭐ 功能：踩住踏板时，**手弹**的 `note_off` **只关 gate、不启动包络释放**（音停在 sustain）；
    ⭐ 松开踏板 ⇒ **所有被留住的音同时释放** ✅
    ⭐ 原理（改动极窄）：包络只看 gate ⇒ `gate_r=0` 但 `sus_hold_r=1`
    ⇒ 引擎看到的仍是 1 ⇒ ⭐ 停在 sustain、⛔ 不进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
    [top_sound_samples.csv]
2026-10-05 chore(evidence): 合并队友（限幅裕量/右手板诊断）后重跑的门③④证据
    ⭐ 合并树（我的 T5 ＋ 他们的 OUTPUT_HEADROOM_SH=2）：
    门① 综合 ERROR=0 · 门③ 干净 PnR 16.2min（.fs · 无 PR0004 · 0/0 · Fmax 56.645 MHz）
    门④ 全量回归 通过 127 / 共 127
    ⭐ 资源：T_Lut 27314 · T_Register 16972 · CLS 78%
    ⭐ 时序对照：队友基线 56.351 · 我的 T5 单版 55.060 · ⭐ 合并树 56.645（最高）
    [top_sound_samples.csv]
2026-10-06 revert(audio): OUTPUT_HEADROOM_SH 2 -> 1（用户拒绝整体音量降 6dB）；改走修法3（电平感知归一化）
2026-10-06 exp(audio): 修法3（电平感知归一化）第一次尝试——已实现但 tb_tdm_render_mixer 红2项，回退并归档设计与失败现象
2026-10-06 feat(audio): 修法3 电平感知归一化 —— 治 3+复音 × 高持续比音色(0/3) 的软限幅削顶
    【根因（已量化）】gain(N) = 64/√N ⇒ 限幅器看到 = Σenv × gain = √N × 0.5 × 2^23
    ⇒ N=3 已 86.7%（正好踩 87.5% 软膝）、N≥4 超 100% ⇒ 与用户「3 个及以上」完全吻合；
    高持续比音色（BASS 0.70 / PAD 0.90）Σenv 更大 ⇒ 先踩线 ⇒ 只有这两个 ✅
    【修法】gain = min( 64/√N , gain_lin_lut(Σenv>>16) )，新增 33 项表（≈108/n_eff，⛔ 无除法器）；
    在 TDM 遍历里与 acc_r 同拍累加 Σenv（零额外加法树）；用 voice_active_i[cnt_sel] 门控
    （只统计真正在发声的声部 —— 否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
2026-10-06 docs(audio): 修法3 落地归档 —— U_merged_levelaware.fs (55.301MHz/0-0)，含量化对照表、门控纪律与调试记录
2026-10-06 fix(audio): 修法3 第二次修正 —— n_eff 四舍五入 + 迟滞 + 目标改 115/n
    【上板反馈】用户实测：3 键及以上**随机**出现轻微爆破；16 键反而轻；单/双音没有。
    ⇒ 推翻"纯电平越界"（16 键电平更低却更轻），指向**档位边界抖动**。
    【根因（量化）】3 声部满包络时 Σenv = 3×65535 = 196605，
    而 gain_lin_lut 的 2→3 档边界 = 3×65536 = 196608 ⇒ **只差 3**
    ⇒ 包络任何微起伏都让 n_eff 在 2/3 间翻 ⇒ 旧 LUT(108/n) 增益 54↔36 猛跳(−33%) ⇒ 爆破。
    📌 系统性缺陷：n_eff = Σenv>>16 是【向下取整】，而每个满包络声部贡献 65535
    ⇒ N 个满包络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
    [tdm_render_mixer.v]
2026-10-06 docs(audio): 修法3 第二次修正归档 —— V_merged_levelaware2.fs (55.294MHz/0-0)，含边界抖动量化表与三个自身失误记录
2026-10-06 fix(audio): C 方案 —— envelope_bank 包络总线【原子提交】，消除帧内 32 拍新旧混合
    【根因（治本）】envelope_bank.v L25-29 自己记录的契约：env_level_o / env_active_o
    是【逐拍落盘】的（voice 0 在 tick+2、voice 31 在 tick+33）
    ⇒ 每次 tick 后 33 拍（33/1024 ≈ 3.2%，正是甲 §七#5 写的"~3%/次分配"）内，
    输出总线是"已服务的新帧 + 未服务的旧帧"的【混合】
    ⇒ 消费者（tdm_render_mixer / note_manager）在该窗口读 ⇒ 包络幅度【突跳】
    ⇒ 顶到 87.5% 软限幅 ⇒ 听感"收音机滋滋声"
    【为什么只有音色 0(BASS, sustain 0.70) 和 3(PAD, 0.90)】
    四个音色里唯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
    [top_sound_samples.csv]
2026-10-06 docs(audio): C 方案落地归档 —— W_merged_atomic.fs (55.406MHz/0-0, +527FF)，含根因契约、tb 加强说明与全量回归清单
    [top_sound_samples.csv]
2026-10-06 feat(audio): A 方案 —— 电平感知归一化目标 115/n → 100/n（余量优先）
    【为什么】115/n 在 N=3 时【不生效】（115/3=38 > sqrt(3)=37）
    ⇒ 输出仍停在 86.7%（软膝 87.5%），余量仅 1%
    ⇒ 高 sustain 音色（BASS 0.70 / PAD 0.90）持续被软限幅咬住 ⇒ 用户实测"收音机滋滋声"
    改成 100/n 后 N=3 生效（33 < 37）⇒ 输出 77.4%，余量 12%
    【效果（满包络）】
    N=1: min(64,100)=64 ⇒ 响度不变 ✅
    N=2: min(45,50)=45 ⇒ 响度不变 ✅
    N=3: min(37,33)=33 ⇒ 86.7% → 77.4%（余量 1% → 12%）
    N=4: min(32,25)=25 ⇒ 6553300（实测，离天花板更远）
    N=32: min(11,3)=3 ⇒ 6.29e6
    【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
2026-10-06 docs(audio): A 方案落地归档 —— X_merged_A.fs (55.899MHz/0-0)；含不可兼得取舍说明与两条残留候选的30秒验证法
2026-10-06 revert(audio): 回退 A 方案（电平项 100/n → 115/n），保留 C 方案
    【为什么回退】用户上板实测：降到 100/n（N≥3 余量 1% → 12%）后症状【仍然存在】
    ⇒ 12% 余量都压不住 ⇒ 根因不在"电平越界/软限幅余量"
    ⇒ A 让 N≥3 响度白降约 1 dB、却零收益 ⇒ 回退，把响度还给用户
    【⭐ 决定性证据（用户测试 B）】按住 3 个键、每秒读一次标定后位置 `N`：
    数据【不断变化】⇒ 霍尔位置读数在持续漂移/抖动
    ⇒ 完整因果链：
    位置读数持续变化 ⇒ vtgt_val[axis]（力度目标）持续更新 ⇒ vel_r 力度斜坡跟着追
    ⇒ ADSR 的 SUSTAIN 电平（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
    [tdm_render_mixer.v]
2026-10-06 docs(audio): C保留/A回退归档 —— Y_merged_Conly.fs (55.406MHz)；锁定根因=霍尔读数持续变化，列出被排除方向与三种修法
2026-10-06 revert(audio): 回退到合并版 56.351 的 RTL 状态（保留队友 T5）
    【用户要求】回到"合并版时序 56 多"的那一版，再加上队友远端的新提交。
    【事实核对】
    · 远端【无新提交】—— 队友的 340f193（T5 延音踏板）+ 0d0c168 早已合入，本地 = 远端
    · 56.351 基线提交 = 2be631f
    【回退了什么（只回退我自己的音频实验，不动队友的）】
    · rtl/w3b/tdm_render_mixer.v ← 电平感知归一化（gain_lin_lut / n_eff / 迟滞）
    · rtl/w3b/envelope_bank.v ← C 方案（包络总线原子提交 / env_lvl_shadow）
    · tb/w3b/tb_tdm_render_mixer.sv ← 新增的第 6 段判据
    · tb/w3b/tb_p5_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
    [top_m0_pa_trace.csv]
2026-10-06 docs: 基线+T5 交付归档 —— Z_merged_base_T5.fs (55.060MHz/0-0)；说明 56.351 是不含 T5 的版本，T5 实打实吃时序
    [top_m0_pa_trace.csv]
2026-10-08 chore(evidence): 合并 main（7c5ad7e）后重跑聚焦验证的 tb 日志刷新
    ⭐ 合并方式：快进（他们的 main 已含我的 0d0c168）⇒ 0 冲突、无 merge commit
    ⭐ 本次验证：tb_note_manager_sus 19/19 · tb_sustain_pedal_wire 9/9 · tb_top_sound / tb_master_mix 等音频链 tb 全绿
    ⭐ 我的 T5 完好：top.v 的 sus_pedal_r 4 处 · note_manager 的 sus_hold_r 11 处 · 两个 tb 都在
    [top_sound_samples.csv]
2026-10-08 docs(丙): guide_lamp 接线说明给甲 —— 曲谱→LED指引最后拼图（只写方案不改代码）
2026-10-08 docs: 第三周组会报告（2026-10-01~10-08）—— 对照第三周计划逐项盘点 + 未完成分类 + 7 条改进项 + 下周优先级
    ⭐ 覆盖：甲 T1~T7 / v2 的 N1~N7 / 乙 H1~H7 / 丙 P1~P5 / 硬件 W1~W4
    ⭐ 结论：三条主线都到可交付状态；当前交付码流 Z_merged_base_T5.fs = 55.060MHz/0-0；回归 127/127
    ⭐ 未完成按阻塞原因分三类（等硬件 / 技术未做 / 质量流程）
    ⭐ 改进项含：先定位根因再动手 · 时序数字必须同树 A/B · 端到端夹具复用 · 上板清单固定化
2026-10-08 chore(evidence): 合并 main（7c5ad7e）后聚焦验证 10/10 全绿的 tb 日志
    ⭐ 全绿清单：tb_note_manager_sus 19/19 · tb_sustain_pedal_wire 9/9 · tb_top_sound · tb_master_mix
    · tb_tdm_render_mixer · tb_velocity_headroom · tb_velocity_lane_isolation
    · tb_velocity_tone_decoupling · tb_note_manager(4/4) · tb_top_m0
    ⭐ 结论：合并队友 15 个提交（含音频治理与回退）后，我的 T5 与全部音频链判据均未受影响
    [top_m0_pa_trace.csv, top_sound_samples.csv]
2026-10-08 docs(hdmi): K-41 PLL 见证归档 + 上板记录表回填（用户指定 ① ③）
    【① evidence/h5/PLL_WITNESS.md（新建）—— K-41 要求的 fVCO 核算 + 活体见证】
    · K-41 原文口径（已知问题与风险清单.md:87）：边界是「⛔ 不用 PLL 输出做全设计系统时钟」，
    外设/TMDS 用 PLL 属正常（K-114）。本设计 clk_sys 仍来自 50MHz 晶振、音频通路不用 PLL ⇒ 合规
    · ⭐ fVCO 核算（生效分支 USE_252=0）：
    fVCO = 50 × MDIV(20) / IDIV(1) = 1000 MHz ← 落在允许区间（约 700~1400）✅
    serial_clk = 1000/ODIV0(8) = 125.000 MHz ← 与 top.sdc:75 一致 ✅
    pixel_clk = 1000/ODIV1(40) = 25.000 MHz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
2026-10-08 revert(docs): 撤回误推的第三周组会报告 —— 组会材料按惯例走 meeting-<日期>/ + .git/info/exclude（本地私有，⛔ 不入库）
    ⭐ 事故：我把组会报告直接提交并推到了 main（10a348a），违反了既有惯例
    （meeting-20260918/ · meeting-20260927/ 都在 .git/info/exclude 里，注释写明 NEVER commit or push）
    ⭐ 处置：文件移到 meeting-20261008/（已加进 .git/info/exclude，git check-ignore 确认生效）⇒ 本提交把它从库里删除
    ⚠️ 注意：它仍在【历史】里（10a348a）—— 要不要连历史一起清，见用户裁定
2026-10-08 docs: 上板清单 + SHA-256（Z_merged_base_T5.fs）—— 按队友建议「一次上板把该验的都验掉」
    出处：第三周组会报告-20261008.md §七 #5「每次合并后固定出一份上板清单 + sha256」
    【烧什么】
    · Z_merged_base_T5.fs · 19,336,303 B
    · sha256 1F938F5D0C0B5D398B97F792D947C9FFE026E008A93F73E1219F730AAB7C3D90
    ⭐ 已与实际文件逐字核对一致 + 与 evidence/h5/base-T5-55p060/README.md 交叉核对
    · 55.060 MHz / 0-0 / CLS 78% / 器件 AC1/I0
    【主任务：T1 的 7 项复验】出处 第三周计划-v1.md:54
    失谐 · 4 音色 · 按音色 ADSR · looper 音色 · S2 切音色 · 串口 B 节拍器 · 鼓机
    （已知 09-30 实测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
2026-10-09 deliver(右手板): 联调档时序达标 —— 一个能上板的版本（=1 档 0/0 · ≈57.0 MHz · 余量 +0.642 ns）
    ⭐ **本提交 = 可上板版本**（⭐ 右手板 `RIGHT_ADC_ENABLE=1` 第一次通过时序）
    ⭐ 涵盖：① 右手板 1630 条 setup 违例定位与修复 ② `N4` 量纲守卫 ③ `A3` 鼓扫频窗口收口
    ════════════════════════════════════════════════════════════════════════
    一、⭐ 上板请用这个位流（⛔ 未入库，`*.fs` 在 .gitignore 里 —— 本地编或找我要）
    ══════════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
    [note_manager.v, oscillator_bank.v, oscillator_bank_ref.v, tb_right_adc.sv]
2026-10-09 deliver(审查+P0): 时序/逻辑全量审查（306 条）+ P0 修复 10 条 + 交付树默认切右手板档 —— Fmax 60.784 MHz
    ⭐ 本提交 = 一次交付：⭐ **全量审查报告 + 第一批 P0 修复 + 基线切到右手板档**
    ════════════════════════════════════════════════════════════════
    一、⭐ 全量时序/逻辑审查（肌肉集团 · 16 路并行 + 1 归档）
    ════════════════════════════════════════════════════════════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
    [top_sound_samples.csv]
2026-10-11 deliver(审查+P0+P1): 全量审查 306 条 + P0 修 28 条 + P1 修 3 条 + 位流归档 + 4 道机械门
    ⭐ 一、审查（地基）
    review/时序与逻辑审查-20261009.md —— 306 条（P0 32 / P1 81 / P2 96 / P3 97）
    16 路并行（12 路模块内部 + 4 路模块衔接）+ 1 路归档 · 覆盖 62 个 RTL 文件 / 18023 行
    ⭐ 二、P0 —— 32/32 全部有交代（28 修 + 2 降级 + 2 回退 + 1 推迟）
    ✅ 28 修：01 02 03 04 05 07 08 09 10 11 13 15 16 18 19 21 22 23 24 25 26 27 28 29 30 32
    ⚠️ 降级 2：06（卫生）· 17（资源 delta = 0）
    🔴 回退 2：12（缺"按下门"）· 14（与 C12 契约冲突）
    ⏸️ 推迟 1：31（鼓起音扫频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
2026-10-11 deliver(timing+审查): 余量标定 17.8 ns（真实余量 +2.2 ns）+ P0-25 改法4 实测无效已回退
    ⭐ 余量标定（本次核心）
    set_max_delay 18.181 → 17.8 ns：真实余量 +0.028 → +2.2 ns（79 倍）
    三次标定：55.087/0违例 · 57.203/14违例 · 56.18/0违例 ⇒ 真实上限 ≈ 57.2 MHz
    位流 sha256 B3125562689BB3328E1F0D28906BAD3B0FAFFA3D4FB6BFBFC2722B78F5299BE1
    ⭐ PnR 是确定性的（清空重跑时序一字不差）⇒ 不存在'队友重跑翻车'风险
    ⭐ P0-25 改法 4 实测无效已回退（(* keep *) 拦不住 Gowin 折掉 x|0）
    这是第 7 次'审查的诊断对、改法必须实测'
    ⭐ HOLD 余量仍 0.049 ns（无 RTL 解，0/0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
2026-10-11 ESP32线：曲谱灌流通路打通 + 修两个会让真谱面放不出来的真缺陷 + 文档一致性审计
    曲谱灌流通路（真机端到端：灌 11865 事件 -> 起播 -> 放完 100%）：
    · 新增 score_word.py —— 64 bit 事件字的【唯一定义处】（36 项自检，含非空洞性）
    · 修 3 处错位域（BLE 主路径 send_frames_ble.py / screen_demo.py / 交接文档自己）：
    2026-09-22 修订后 FPGA 用 inc[43:23]/axis[22:19]/vel[18:11]/timbre[8:7]，
    而这三处仍是旧布局 => FPGA 会解出 inc>>1（低一个八度）、且 inc 最低位渗进
    axis 把轴号污染。长期没暴露：固件只读 tick/kind（两布局这两字段相同），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
2026-10-11 deliver: ESP32 独立 UART + 曲谱链路打通（含 1024 倍音高量纲修复）+ 录制回传 + P1-18/P1-59
    本周期（2026-10-11）交付，全部经全量回归 + PnR 验证。
    ═══ 一、曲谱链路：从"结构上不可能工作"到"端到端能出声" ═══
    修掉三处让它不工作的缺陷：
    1. play_seq 从未被例化（缺事件缓冲）=> 新建 U-19 evt_buf（8 KB / 1024 事件，4 BSRAM）
    + 在 top.v 例化 play_seq + guide_lamp（复活 LED 指引）。
    2. P0-02 门控里 & (cmd_idx == 4'd0) 是错的 => 曲谱载荷 9 个字节只有 1 个过门
    => 整条链路不可用。改为只保留 ~ui_in_frame。
    3. 🔴 曲谱音高的 1024 倍量纲错（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
    [calib_cmd.v, drum_gen.v, evt_buf.v, looper.v, note_manager.v, oscillator_bank.v, oscillator_bank_ref.v, rec_dump.v]
2026-10-12 ESP32线：修 6 个真缺陷 + 曲谱/回传上位机 + 全量测试执行器
    ═══ 一、修的 6 个真缺陷（⭐ 每个都有真机前后对照）═══
    1 🔴 BTC_TASK 栈溢出 ⇒ 起播约 20 秒后板子必崩重启
    取证：新增 _crash_capture.py（当场 flush+fsync 落盘，⛔ 不用攒到最后才输出的工具）
    现场：***ERROR*** A stack overflow in task BTC_TASK has been detected.
    Rebooting... rst:0xc (RTC_SW_CPU_RST) => 固件崩溃，⛔ 不是掉电
    （⭐ 负面证据也留了：日志里没有 Brownout 提示）
    修法：CONFIG_BT_BTC_TASK_STACK_SIZE 3072->6144 / BTU 4352->6144
    ⚠️ 改 sdkconfig.defaults（入库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
    [ble_main.c]
2026-10-12 ESP32线：断链后重连恢复「就绪」+ 断连事件竞态 + 状态计数器
    ═══ 一、功能 ═══
    · LINK_LOST 恢复（用户 2026-10-12 裁定）：重连成功 => 屏上显示「就绪」
    未修前：断开置 LINK_LOST，重连后无人复位 => 屏上一直挂「断链」，
    直到有新数据才被动走掉。用 READY 而⛔ 不是 IDLE —— IDLE 语义是
    "池是空的、什么都没装"，而重连时池里往往还留着上一曲的谱。
    · 顺带修真竞态：DISCONNECT_EVT 原来【无条件】清理并置 LINK_LOST，
    不校验 conn_id。Bluedroid 回调异步投递，重连够快时旧连接的 DISCONNECT
    可能晚于新连接的 CONNECT 落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
2026-10-12 落实 FPGA 侧「上行帧格式 v1.1」+ 同步 5 份回复 + 修端口探测的一个真缺陷
    ═══ 〇、先说一个【11 天】的失误（⭐ 比代码值钱）═══
    我方交接文档一直写着「FPGA 侧未回函 / 无回应」—— 🔴 那是错的。
    FPGA 侧 2026-10-01 就答复了，而且不止一份，共 5 份。
    为什么没看到：他们把回复写在【主 worktree】FPGA2026/files/20-代码/，
    而我方一直按 FPGA2026-esp32/files/20-代码/ 找。
    两个 worktree 是同一个仓库，但 files/ 内容不同，
    且没有任何机制把回复同步过来 => 空了 11 天。
    ⭐ 教训：「对方没回复」这个结论，必须先证明【找过所有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
2026-10-12 答 FPGA 侧两个确认 + 补 last_seq 口径的判据 + 记下 9B 回传帧这个新发现
    ═══ 一、FPGA 侧已回复（本次直接写进 esp32 worktree，没再漏）═══
    新增：`FPGA侧答复-上行帧v1.1确认-20261012.md`（03-12 23:29）
    他们接受了我方建议【两处都写】：
    · `FPGA2026-esp32/files/20-代码/` 一份
    · 主 worktree 一份（同名）
    => 两道保险，不依赖人工同步（比我们建议的还稳）。
    ⚠️ 他们提了一条约束，我方记下并回函承诺：
    两个 worktree 共享同一个 .git => 【变异测试运行期间不能有另一个
    worktree 的 git 写操作】（会互相覆盖文件）。
    我方跑变异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
2026-10-13 本周期交付（2026-10-10 ~ 10-13）：滑音判据+开关+音高通路、BPM 串口入口、P0-25 根治、4 条 P1、2 道新机械门、ESP32 协议对齐
    【滑音（portamento）】
    - 判据 5/5：tb/w3a/tb_event_extract_slide.sv（一减一增+相邻+窗口内 => 出滑音；
    两轴都增/非相邻/只有 A 在减 => 不许报；+ 非空洞守卫）
    - 判据逻辑：邻居表（12 对水平相邻，物理布局不是轴号）+ 窗口 1000 帧 + 起滑阈值 12'h040
    - 'W' 串口开关（第 21 条命令，默认关）+ slide_en_i（Z-safe）+ slide_on_r + P0-29 门
    - 音高通路：event_extract 输出 B 的轴号 -> axis_map 第二查表口（只读 fb_inc 省一半 LUT）
    ->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
2026-10-13 deliver(merged): integrate E scope with teammate BPM and slide; archive candidate STA
    Original: local Q scope control collided with teammate Q framed BPM. Correction: E switches waveform/XY, B remains metronome, Q sets BPM from the next framed payload and W toggles slide. The command uniqueness table contains all 22 entries. Preserve teammate eda1a71 and all local functions.
    Retain corrected looper wire-pitch units, atomic dual-UART export with rejection accounting and deferred complete probes, independent-OE TLC5916 scan and guide timing, qualified ADC fault windows, Test Mode default, event-buffer clear/drop collision fix, phase-continuous audio and HDMI reset handling. Keep the fixed-cyc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
    [project_input_sha256.csv, rtl_sha256.csv, test_mode_n16.csv, test_mode_n16_peaks.csv, test_mode_n32.csv, test_mode_n32_peaks.csv, test_mode_n4.csv, test_mode_n4_peaks.csv]
2026-10-13 MIDI 回传端到端演示 + 修两个真缺陷（tick 单位 / 变长量无上限）+ 答 FPGA 侧
    ═══ 〇、一句话 ═══
    "FPGA 回传事件 -> PC 存谱 -> 转 MIDI 能播" 这条链，
    **离线端到端已经打通并用判据钉住**；音高与时间都逐点核对过。
    真机那一半仍在等 FPGA 侧实现 14 B 发送（他们已确认未实现）。
    ═══ 一、演示：demo_midi_roundtrip.py（新增，已登记进执行器）═══
    它做四件事，每件都有独立判据：
    1 按 v1.1 造一段"FPGA 会发上来的字节流"
    111 个事件字（demo_scale.hex，C 大调音阶）=> 14 B 帧 + 0x05 锚点 + 0x10 表帧
    判据：帧数公式对得上 /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
2026-10-13 新增 ESP32 上机手册 + 修线上校验的抓取窗口（会偶发假红）
    ═══ 一、ESP32上机手册-20261013.md（新增）═══
    回答两个问题 + 一份能照着做的操作手册。
    〇、板子是不是"完全板"、能不能做 FPGA 联调
    · 硬件：是。ESP32-S3 N16R8（16MB Flash + 8MB PSRAM），三路 UART 全部实装并实测
    · 联调：下行能，上行还差 FPGA 侧两项 —— 且都【不是我方的缺口】
    1 G21/G22 引脚未分配（FPGA 侧 PMOD0）=> ESP32 与 FPGA 电气上还没接
    2 FPGA 未实现 14 B 实时事件帧（现在只发 9 B 回传帧）
    3 tick 单位未裁定（两份 FPGA 文档冲突）
    旁证：FPGA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
2026-10-13 deliver(slide): real portamento ramp + fretboard/piano mode toggle; CLS +6 only
    THE PROBLEM. Slide did not glide -- it jumped. A controlled experiment on the
    real top.v (tb/top/tb_slide_e2e.sv: same synthetic gesture, only am_mode
    changed) showed why the feature looked dead and why it was NOT an algorithm
    problem: the detector fires correctly for the physically adjacent pair 6->7,
    and with am_mode=1 the sounding voice lands EXACTLY on fb_inc[7] -- but with
    am_mode=0, which is the delivery default, the pitch does not move at all.
    The gate is the slide term in top.v's pitch_upd mux, and MODE_PIANO_DEFAULT=1
    makes am_mode=0, so the term is structurally zero.
    1) REAL GLIDE -- rtl/w3a/slide_ra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
    [calib_cmd.v, ctrl_key_map.v, ctrl_keypad.v, slide_ramp.v, tb_axis_map.sv, tb_ctrl_keypad.sv, tb_slide_e2e.sv, tb_slide_ramp.sv]
2026-10-13 🔴 修 BLE 广播包长度错误（导致 PC 扫不到设备）+ 网页进度真值
    ═══ 一、真缺陷：广播包名字被截断 => PC 扫不到设备 ═══
    这是这几天"找不到设备"的【真正根因】。
    🔴 症状：板子日志全程说成功
    （config_adv_data_raw OK / adv data set / advertising as "..."），
    但 PC 侧收到的广播包是【空的】：
    local_name = None · manufacturer = {} · service_uuids = []
    只有 rssi = -39（信号很强 => 确实收到了广播）
    => 所有 BLE 工具报"没找到设备"，看起来像板子没广播。
    🔴 根因（两个缺陷叠在一起，都在这几行里）：
    缺陷 A（原来就有）：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
2026-10-13 🔴 根因修复：BLE 服务发现只有 4 个 —— Windows 按 MAC 缓存 GATT 表，改用随机地址
    ═══ 症状 ═══
    PC 连上板子后，只能发现 4 个 GATT 强制特征（2a05/2a00/2a01/2aa6），
    我们自己的 0xABF1~0xABF4 一个都没有
    => BleakCharacteristicNotFoundError（0xABF3 not found）
    => 所有 BLE 工具全线失败，看起来像"链路不通"。
    ═══ 排查过程（每一步都有判据，失败尝试也记下）═══
    1 板子侧自证正常：
    attr table created OK + 句柄 40/42/44/47/49 + service started
    => 服务确实注册并启动了。
    2 板子复位 / 重烧固件 => 无效
    3 改设备名（Synth -> Synth2）=>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
    [ble_main.c]
2026-10-13 落文档：BLE 根因（§7.6）+ 下行贯通 + 给 FPGA 侧的回函
    ═══ 一、交接文档新增 §7.6：BLE「服务发现只有 4 个」的根因 ═══
    ⭐ 这条务必先读 —— 它的症状看起来像"链路不通"，实际是 PC 侧的缓存，
    不知道这一点会去查 RTL / 查固件，白费几小时。
    根因：Windows 按 MAC 地址缓存 GATT 服务表，认定本设备只有 4 个服务
    => 根本不发起服务发现。
    判据链（⭐ 这条链比结论值钱）：
    1 板子日志全正常（attr table created OK + 句柄 40~49 + service started）
    2 复位 / 重烧固件无效
    3 改设备名无效 => ⚠️ 缓存键是 MAC，不是名字
    4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
2026-10-13 补 3 个「有判据但没人跑」的工具 + 修 selftest_all 的收录缺口
    ═══ 〇、修的是什么缺口 ═══
    🔴 `selftest_all.py` 原来【一律跳过 `_` 开头的脚本】。
    后果：我给 `_uart1_wire_check.py` / `_upstream_loop_check.py` 补的
    `--selftest` **永远跑不到** => 判据等于白写。
    ⭐ 同族：`_stress_cycles.py` 也踩过同一个坑，当时的修法是"登记进
    run_all_tests" —— 但那要【一个个记得登记】，是补丁不是不变量。
    修法（结构性的）：
    ⭐ 规则改成「`_` 开头的【也收录】，但只收【真有 --selftest】的」。
    判据锚在 `has_selftest()`（看 argparse 是否真注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
2026-10-13 新增「只靠 BLE 验 UART1 发送路径」—— 把"ESP32 没发"与"线没接"分开
    ═══ 〇、为什么需要这个工具 ═══
    🔴 本轮踩的坑：CH340 没接时，`_uart1_wire_check.py` 只会说
    "一个字节都没收到 => USB-TTL 的 RX 没接到 GPIO17，或没共地"。
    ⚠️ 它【分不清】是 ESP32 没发，还是线没接 ——
    于是"ESP32 侧到底好不好"这个最基本的问题反而答不了。
    新工具把这两件事分开：
    灌谱 → 起播 → 轮询 0xABF4 的 `sent`（= UART1 实际发出的帧数）
    · sent 稳步增长 => ⭐ ESP32 侧发送路径正常 => 问题在接线/对端
    · 过了提前量仍恒为 0 =>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
2026-10-13 判据粒度：把「缺硬件」与「被测对象坏了」分开（regress_live + e2e）
    批次含：e2e 清池/起播改走 BLE；unk/ovf/mm 改增量判据；regress_live ⑥⑦ 前置化；e2e 帧数前置化。真机通过项 11 -> 13。
2026-10-13 落文档 §7.8：真机验收状态 + 连续 3 轮零抖动证据 + 4 条独立判据
    全量连续 3 轮：通过 13 / 失败 2（零抖动）。BLE 相关项单独 3 轮全绿 12/12。剩余 2 项均为 CH340 接线，非代码。
2026-10-14 修进度条分母(ttot) + 修 pump 周期(tick 100->1000Hz) + 给 FPGA 的问题清单
    ttot 改为取全帧 tick 最大值（原来取末帧，多轴交织时错）实测 19200->100320；FreeRTOS tick 100->1000Hz 实测 pum 9996->2065us；新增 7 条问题清单交 FPGA 侧。
    [ble_main.c]
2026-10-14 deliver: 'A' + vibrato board-verified; bar-aligned manual BPM; absorb the ESP32 and AT lines
    One cycle, squashed. Board-verified, merged two teammate lines, and fixed the
    two things the user reported after flashing.
    === 1. The two reported bugs are BOARD-VERIFIED ===
    User flashed the 2026-10-14 00:20 bitstream and reported back:
    * 'A' mode switch WORKS (was: "sending A did not reply and both modes
    sounded identical" -- the byte_is_cmd gate)
    * vibrato fader WORKS (was: "the second fader does nothing until
    the very bottom" -- the clamp)
    * BPM can be set (was: "Q60 does nothing")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
    [acceptance_logs_sha256.csv, artifact_hashes.csv, build_inputs_sha256.csv, inputs_before.csv, product_provenance.csv, rtl_sha256.csv]
2026-10-14 交付 FPGA 侧 §十 请求：inc 探针 + 回函；并补登记 4 个新工具
    新增 _gen_inc_probe.py（末帧可核对的最小谱面，17 项自检）与 _inc_scale_probe.py（由 A4 锚点反推放大倍率 = 2^10，误差 0.0007%，7 项自检）；据此得出「下行路径越界放大不成立」（21 位满量程 x1024 = 2^31）；补齐 score_word 的 TIMBRE_* 常量；回函收回上一封的错误结论（鼓轴号冲突 —— 读到的是 FPGA 侧第 1 版）。离线全量 31 工具 / 706 项 / 0 RED。
    [inc探针-最小谱面-20261014.csv]
2026-10-14 起播等待 10.4 秒 -> 1.81 秒；动态提前量模型推演与两版失败记录
    按 FPGA 给的缓冲参数（HIGH_WM=768）重做提前量。连错两版（填满缓冲 => 363 秒荒谬；攒一次停顿 => E 被约掉成常数），第三版承认它基本是常数，把固定值 20000 降到 1200 tick。真机实测首帧 1.81 秒。新增 _lead_model_check.py 记录三版推演。
2026-10-14 回传整合进灌谱页（共用一条 BLE）+ 修 pool_stop 挂音 + 修三处口径/缓存问题
    pool_stop 补发未闭合的 note_off（真机验证 on-off 差 1、补完 still_open=0）；回传逻辑整合进 score_studio.html 并共用 BLE 连接；修 inc->Hz 时钟（50M -> 48.828125M）与 PPQN（480 -> 960）；发现校验覆盖范围与 FPGA 文档冲突（已钉住待裁定）；三个页面加防缓存 + 构建时间戳。
2026-10-14 鼓谱转换（GM->鼓机四件）+ 选轨播放 + 轴图例显示音色 + 发现下行 inc 位宽硬冲突
    鼓原来按 GM 音高当乐音发（用户报'听着怪'），改为映射到鼓机四件并全走 axis 15；新增选轨播放（按源轨过滤，换速事件恒保留）；轴图例显示音色名；实测发现下行 21 位 inc 装不下鼓机的 32 位值（四个全超），已列阻塞并写追问文档。
2026-10-14 新增需求文档：让 PC 灌的鼓谱正确发声（下行 inc 21 位装不下鼓机 32 位）
    含三条可选方案（低2位查表 / 加宽字段 / 走键盘打鼓那条路）、实测数据、以及两条请 FPGA 侧确认的口径（校验覆盖范围、GM 鼓映射）。文档里所有数字均与实测核对。
2026-10-14 修网页显示层：C10（采样时钟写错）+ 鼓显示成 BASS；并同步 FPGA 侧校验口径更正
    灌谱页 F_CLK 50M -> 48.828125（与回传页同源错误，上轮漏改），越界音高明确标注；鼓轴图例显示'鼓'并列出四件件数；新增 _display_check.js 把这两个错误钉成回归测试。另同步 FPGA 侧答复第3版（校验覆盖范围已更正为含 0xA5，与我方一致）。
2026-10-14 按 FPGA 第3版答复修正：inc = phase_inc>>10（我方位宽结论作废）；回退 F_CLK 误改
    我方的'21位装不下鼓'前提错了（RTL 取的是高21位）；真因是来源标记 SRC_SCORE 不被鼓池认。四个鼓字段值与 FPGA 表格完全一致。另纠正我自己把灌谱页 F_CLK 改成 48828.125 的误判（两个页面口径不同）。
2026-10-14 修和弦没被识别（FPGA same_hit 顶音）+ 鼓单独一栏 + 追问同时敲鼓
    和弦：按音色合并 axis 导致同轴多音互相顶掉，改为按段贪心分配 axis（真同时 9->1）；鼓：从钢琴卷帘移出、底部独立 4 轨显示；顺带修我自己引入的 midi=undefined 变调 bug；发现鼓轴同 tick 多敲 568 次的重叠问题并写追问文档。
2026-10-14 同步交接文档：补本轮四条新事实（axis 语义 / 鼓 / 提前量 / 上行状态）
    ═══ 一、⭐ 新增「axis 的两条必须知道的语义」═══
    1 ⭐ axis 对曲谱事件只是【标签】—— 音高由 inc 直接携带
    出处：seq_arb.v:333 `evt_axis_o <= pop_data[AX_O +: AXIS_W]`
    2 🔴 同一个 axis 上、同一来源的音会【互相顶掉】
    —— note_manager 里每个 (axis, src) 最多只有 1 个在响的 voice
    出处：note_manager.v:870 + same_hit = live_mask & (axis_r==cur_axis) & (src_r==cur_src)
    ⭐ 推论：和弦的每个音必须落在不同 axis 上（否则只有 1 个音发声）
    这是我方"和弦没被识别"的根因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
2026-10-14 修两个用户报告的问题：GATT operation already in progress + 一键上传只有 3.6 KB/s
    ═══ 一、`GATT operation already in progress` ═══
    🔴 根因：本页有【三处】会同时发 GATT，而 Web Bluetooth
    同一时刻只允许【一个】GATT 操作在飞：
    · 轮询 pollOnce()（每 1.2 s：写 CMD 0x02 + 读 STAT）
    · 灌谱 upload()（连续 writeValueWithoutResponse）
    · 起播/停止/清池（sendCmd）
    ⇒ 并发就报这个错。用户实际就是在灌谱时看到的。
    ⭐ 修法（结构性，⛔ 不只在灌谱处加锁）：
    加 gattSerial() 串行队列 —— 所有 GATT 操作排队执行。
    ⭐ 将来新增任何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
2026-10-14 🔴 修 BPM：全局 BPM 的谱子被兜底成 120（tempo 轨没音符 ⇒ 整个被丢）
    ═══ 用户报告 ═══
    "`09_Conjurer.mid` 这个 midi 是 168 bpm，但是我听着感觉是 120 的。中间无变速"
    "因为有一个全局 bpm 啊，很多谱子根本没有变速点"
    ═══ 查证（两个缺陷叠在一起）═══
    🔴 缺陷 1（真根因）：**tempo 轨被整个丢掉**
    实测：那把 MIDI 的 7 个 tempo 事件全在【轨 0】（tempo track），
    而轨 0 只有 tempo + time signature，【一个音符都没有】。
    ⚠️ parseMidi() 按"有没有音符"过滤轨：
    if (tr.notes.length) tracks.push(tr);
    ⇒ tempo 轨被丢 ⇒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
2026-10-14 夜间自检工具三件套 + 待上机验证清单；确认无工具依赖固定 axis
    新增 _undef_check.js（未定义函数引用，本轮踩过 2 次）、_axis_dep_check.py（本轮改动态分轴后必须核）、待上机验证清单（6 步含命令与预期输出）。_axis_dep_check 结论：全仓仅 2 处硬断言且均安全，无工具依赖固定 axis。
2026-10-14 fretboard multi-axis voice tracking + keypad/LED/guide-mode/14B upstream
    指板模式重写成多轴独立跟踪（治挂音 + 第二个音出不来 + 滑音失效）：
    - held_mask / sounding_mask / rot_q 轮转指针取代单个 gate_axis
    - 环形扫描：从上次拨的轴之后开始扫，扫完一圈回起点
    - 单轴重复拨弦照常；多轴逐个触发；松任意轴放掉正在响的那个
    - P0-22 两条既有契约零回归（滑品后松手 / 键盘->指板切换）
    - tb_play_mode_ctrl 14/14 全绿（原 8 条 + 新增 M1~M5）
    - perc_env_bank DECAY_STEP 67->33（鼓衰减 20ms->40ms，峰值不动不削顶）
    - 新增 P3b 判据：时长必须与 DECA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
2026-10-14 夜间第二轮：双向验证四组判据 + 修写死端口 + 清单命令可粘贴化
    新增 _bidir_check.py（把四组修复改回旧写法，判据必须红）；补 _midi_parse_check 的'多 tempo 全发'判据（双向验证抓到的真漏洞）；修 _uart1_wire_check 写死 COM29 改为 --log-port 按 VID 解析；新增 _doc_cmd_check.py 保证待上机清单的命令可粘贴且参数存在。
2026-10-14 交接 prompt 更新基线数字并加上机清单指引
    selftest_all 期望从 19 工具/317 项 改为 41 工具/856 项；新增第 4 步直接指向待上机验证清单。
2026-10-14 fix(play_mode_ctrl): drop the pluck_d dual-driver so synthesis passes
    上一个 commit 里 pluck_d 被两个 always 块驱动（独立沿检测块 + 主 always 的
    复位）=> Gowin 综合报 EX2000，模块降级为 black box，PnR 直接失败。
    pluck_d/pluck_end 已由 rot_q 轮转指针取代，整个删掉。
    - play_mode_ctrl: 删除独立 pluck_d always 块与主 always 里的复位行
    - 只留注释说明这条纪律（同一 reg 只能有一个 always 块写）
    - tb_play_mode_ctrl 14/14 仍全绿
    [play_mode_ctrl.v]
2026-10-14 网页 UI 三项：鼓换青色 + 图例只留音色 + 音色网页上直接改
    鼓色 #ffb020->#00d5c8（避开与 BASS 橙同色系、避开与变速线黄撞）；图例只列出现过的音色+鼓、不再写轴号；音轨面板加音色下拉，改了会重跑转换并重新灌谱（timbre 要跟着事件下发）。顺带修 drumMapped 累计翻倍、timbreIdx 加错对象两个真 bug。
2026-10-14 docs(上机手册): 2026-10-14 合并版 —— 可测功能清单
    新增 files/20-代码/上机手册-20261014.md：
    - 位流 sha256/size/时间 + 时序资源（0/0 · Fmax 61.022 MHz · CLS 86%）
    - 本轮 8 条新功能（N1~N8）的测试步骤与判据：
    N1 指板多轴跟踪（交替不挂音 / 第二音能出 / 按住重复触发）
    N2 鼓声变大（DECAY_STEP 67->33）
    N3 PC 灌的鼓进鼓池（axis==15 => SRC_KDRUM）
    N4 'Y' 导出 14B v1.1 帧
    N5 looper 武装中黄快闪（治"第一个音被吞"）
    N6 'U' 指引模式
    N7 空循环 'L' 被拒
    N8 'O' 实时上行 + XOR 含 0xA5
    - 全功能清单（键盘/合成/节奏/控制板/显示 共 30 项）
    - 25 条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
2026-10-14 fix(top): Z-safe ctrl_col_i; add the missing evt_upstream.v; green the suite
    全量回归：169/169 全绿（此前 163/169，6 个失败全部定位并修复）
    【我的缺陷 —— 2 组共 4 个】
    1) ctrl_col_i 悬空(Z) 导致 X 传播（tb_demo_stall_diag / tb_e2e_key_to_sound）
    113 个 top 级 tb 里 107 个不接这个端口 => Z => ctrl_keypad.v:93 的
    ~col_i = X => 幻影按键 => 键盘按了不出声。
    修：top.v 边界做 Z-safe 归一（与 enc_a_i/b_i/sw_i 同一个模式，4 LUT）。
    为何不改 107 个 tb：符合 ctrl_keypad 自己写明的契约（悬空=列全高），
    且上板更稳（控制板排线松时不出幻影按键）。
    2) rec_dump 9B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
    [evt_upstream.v, tb_top_dump_atomic.sv, tb_top_probe_queue.sv]
2026-10-14 docs(上机手册): 更新到全绿版位流 + 标注 LED 是【同拍】不是提前
    - §〇 位流表更新：21:01:00 / sha256 29284DA1... / git 458c6a99
    并说明与上一版的唯一差别（ctrl_col_i 的 Z-safe 归一）
    以及 evt_upstream.v 补入库这件事
    - §六 全量回归：未跑 -> 已跑（通过 169 / 共 169 全绿）
    - §N6 指引模式加诚实标注：现在 LED 与音符【同拍】亮，没有提前
    附代码依据（guide_lamp 吃 ps_note_valid；play_seq 是 evt_tick <= cur_tick_r）
2026-10-14 docs(效果器): 整合方案 —— 按用户六条裁定更新，并清掉装饰 emoji
    新增 files/20-代码/效果器链-整合方案-20261014.md（九节）。
    关键内容：
    - 赛题拓展要求 2 点名混响/延迟/合唱；原文有"等"字 => 失真/fuzz/颤音也算数
    - 现有资产：build/fx_parked/fx_delay.v（308 行）判据 20/20 全绿，
    覆盖 delay + chorus；停放原因是分工不是技术
    - 资源更正：预研文档说 BSRAM"只用了 1 块(0.8%)"，实测 69/118(59%)，
    涨了 4 倍多，那份结论不可再引用
    - 加效果器链后：BSRAM 85/118(72%)、LUT 69%、CLS 87%（CLS 是瓶颈）
    用户裁定（2026-10-14）：
    - 失真只做硬削，留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
2026-10-14 feat(guide): LED 提前一拍 + 构建超时提到 40 分钟；补齐本轮文档
    LED 指引提前一拍（用户裁定：方案 C，提前量 1 拍）：
    - play_seq 新增 lead_i 端口：事件在 evt_tick - lead_i 就发出
    lead=0 时比较式与原来逐位相同（零回归）
    用 21 位相加防回绕（20 位会在曲子末尾误发后面的事件）
    - top.v：ps_lead = guide_only_r ? 960 : 0（960 = PPQN = 1 拍）
    - 4 处例化全部显式接 lead_i（悬空 = Z 会导致 X 传播，本轮刚踩过同类坑）
    - 新增 tb/w3c/tb_play_seq_lead.sv，13 条判据全绿：
    L1 lead=0 逐位不变 / L2 精确提前 960 / L3 每条事件都提前
    L4 21 位相加（附 L4b 反证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
2026-10-14 docs(效果器): 按用户新裁定重排路径 —— 不用 EC11，改推子参数页 + 串口屏
    用户修订（2026-10-14 晚）：
    - 串口归属：打通后默认接屏，不再走 PC 发指令；屏未打通期间维持 PC
    - 不用 EC11（不够直观），效果选择与开关改走串口屏直接点选
    - 效果参数调整改走右手板推子参数页
    - 失真增益用连续（DSP 余 96 个，够）
    新增 6.5 路径总览，分四条：
    A 音频信号路径：128 振荡器 + 节拍器/鼓机 -> tdm_render_mixer -> fx_chain
    -> master_mix -> i2s_tx（板载 HP_DIN / 外置 I2S2）
    fx_chain 内部 5 级：失真 -> 合唱 -> 延迟 -> 混响(留位直通) -> 音量颤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
2026-10-14 docs(效果器): 按用户四条再修订 —— 串口编译期二选一、2 位 gear、控制板 8 颗灯
    用户修订（2026-10-14 深夜）：
    - 串口归属不留运行入口，直接在码流里二选一（编译期参数）
    - gear 不需要 3 位，2 位够用 => 复用档 2（原摇把预留）当"效果"页，零位宽改动
    - 右手板没有按键，所有按键都在控制板 4x4 矩阵上
    找到并引用权威文档 files/20-代码/控制板16键功能映射-20261013.md（第 3 版）：
    - 控制板是 8 颗 WS2812（不是 7 颗），第 8 颗就是留给效果器的
    第 3 颗是"推子功能"（变调/颤音/摇把），正好承载新增的"效果"页
    - 键映射：行1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
2026-10-14 docs(效果器): 澄清 led_indicator 是三层结构里的指示层（不是 WS2812）；灯序一起改
    用户问 led_indicator 是什么，用代码澄清：
    各子系统状态码 -> led_indicator（指示层，表驱动，输出 N_CH*24 位颜色）
    -> top.v 的 case 接到驱动写口 -> ws2812_driver（PHY，800kHz 单线）
    -> dout_o -> ctrl_ws_o(C22) -> 控制板灯带
    所以 led_indicator 不知道 WS2812 协议，ws2812_driver 不知道"推子功能"是什么。
    改灯序 = 改 led_indicator 的颜色表，灯带协议层不用动。
    待定 H 已裁定：控制板第 3 版的灯序重排与效果器【一起做】
2026-10-15 feat(fx): 效果器链（失真/合唱/延迟/音量颤音）+ 控制板灯序按第 3 版重排
    一、效果器链模块（纯新文件，不碰任何现有模块）
    fx_dist.v（判据 22/22 绿）—— 数字失真
    · 硬削 + 连续增益（Q4.12，真乘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
2026-10-15 merge: 队友 BJ 冻结版 + ESP32 两项需求 + 效果器链；并修 4 处问题
    一、合并队友的 codex/release-bj-20261015（BJ 冻结版，时序收敛）
    零冲突（唯一共同改动的 rtl/top.v 被 git 自动合并）。
    队友的实测：SetupViol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
    [n16_peaks.csv, n16_spectrum.csv, n32_peaks.csv, n32_spectrum.csv, n4_peaks.csv, n4_spectrum.csv, n8_peaks.csv, n8_spectrum.csv]
2026-10-15 feat: 鼓机多声部 + 逐事件引导 + 效果器运行时参数 + 三刀时序修复
    功能
    - 方案B 鼓分四轴 12/13/14/15（Kick/Snare/HiHat/Tom），旋律轨退到 0..11
    - bit6 逐事件只亮灯不出声：屏/上位机逐条指定，含提前一拍；不占 voice
    - 键14 = 一键恢复默认音高（列2行3）
    - 心跳灯三态：摇杆中位常亮 / 有故障快闪 / 离位照闪（回中观测量有了真消费者）
    - 指板一次拨弦出和弦（经用户授权的 P0-22 契约变更，松某轴只放该轴自己的音）
    - 延迟干湿律改 send/return（原音不衰减，修突兀地响两下）；合唱不再吃反馈
    - 失真 gain/trim 量程 x256（上限 7.9x 到 31.5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
    [all_inputs.csv, bypass_inputs.csv, synthesis_inputs.csv, top_sound_samples.csv]
2026-10-16 fix(时序+约束+鼓标记): 滑音判定链 67→9 级 · 恢复 h5_scope 约束 · 上行鼓标记三路统一
    ## 一、时序（本轮主线）
    - `rtl/w3a/event_extract.v` 滑音 B 选择：**16 级串联比较链** ⇒ 4 级两两合并树 ⇒ 再 ⇒ **2 邻居直选**
    · `Logic Level` 67 → 33 → **21**（综合 `Actual Fmax` 19.505 → 40.503 → 50.365 MHz）
    · 真 PnR：**55.571 MHz / Logic Level 9**（改前 15.052 / 67）· 违例 304 → 226
    · 关键洞察：候选**最多 2 个**（`is_h_adj` 门控），⛔ 不需要 16 路 argmax
    - 🔴 **同时修一个真 bug**：`left_ax_n` 取【最大】轴号 —— 原循环丢了 `!left_hit` 短路，
    而 HEAD 与 `:328`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
    [drum_gen.v, event_extract.v, evt_upstream.v, guide_lamp.v, seq_arb.v, tb_ee_multileave.sv, tb_ee_multineighbor.sv, tb_top_upstream_timbre.sv]
2026-10-16 fix(滑音+LED) + docs(排查): 滑音被噪声抢 A · LED 示范段不亮 · 六路只读审计结论
    一、滑音几乎不触发（用户实测："指板+滑音都开着，依旧很难触发"）
    - 🔴 根因：`event_extract` 选 A 的规则是"轴号【最小】的那个 `delta < -DELTA_TH`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
    [event_extract.v, tb_ee_slide_noise.sv]
2026-10-16 fix(时序+审计): calib 夹紧寄存器化 · 滑音 A 判据改用 key_on · 9 处静默失效 + 6 处卫生
    本周期把「六路只读审计」查出的真缺陷全部落地。判据全绿，PnR 出位流。
    一、时序（本轮主线）
    ⭐ calib 夹紧上界寄存器化 —— 综合报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
    [calib.sv, ctrl_key_map.v, drum_gen.v, event_extract.v, evt_upstream.v, guide_lamp.v, seq_arb.v, tb_ee_multileave.sv]
2026-10-16 时序收敛 + PnR 破卡死 + LED 重播修复：0 setup / 0 hold 位流出炉
    本周期把「PnR 卡死 4 次 + 130 setup 违例」干到「0 setup / 0 hold + 位流出炉」。
    位流：build/bitstreams/20261017-040405-T1-0setup-0hold.fs
    sha256 C5476990997AB809A9C638EF62088AEC332D8154BD16AD10E45FD9ED8B35B299
    Fmax 60.976 MHz（约束 50）· 构建门全过 exit 0
    一、🏆 两处改动各自解决不同问题（都是实测驱动，⛔ 不是抽签）
    ════════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
    [calib.sv, oscillator_bank.v, tdm_render_mixer.v]
2026-10-17 Q3 鼓池超订修好(RESERVED_N 5到8) + Q8 订正 + 文档
    【Q3 真缺陷】原注释写"节拍器 1 + 鼓机 1（共用轴号）=> 需要 2 => RESERVED_N=5 够用" —— 错
    鼓机不是一个 voice：SEL_DRUM=1 档下 drum_gen 走【四件套】(Kick/Snare/HiHat/Tom)
    ＋ 键盘/灌谱鼓最多再 4 个 => 正确需求 8~9 => 池 5 是【超订】
    后果：不是丢事件，而是抢占+偷声；或保留 voice 溢出到 ADSR => 重演 K-144 挂音
    8 处同步改（不许半改 —— cfg_warn_o 只判 <1、漏判 PERC_N => 半改不告警）：
    top.v 4 处 .RESERVED_N (5)->(8) + localparam PERC_N = 8
    rtl/w3c/drum_gen.v:85 与 rtl/w3c/metronome.v:50 的默认值
    tb/e2e/tb_e2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
2026-10-17 源码对齐位流 + Q4 结论 + 上板卡
    【RTL 退回 65aa3c76】⭐⭐ 关键：让源码 == 位流的源码
    Q7/Q2/CLS 那 18 行让 T_Lut 从 34000 涨到 34308(+308)，PnR 三次全卡在 Routing Phase 0->1
    (18 行不值 308 LUT => 是布局/推断的连锁反应，不是逻辑量)
    => RTL 逐字节退回 => 源码与 20261017-065158-Q3-drum-pool-8.fs(0 setup/0 hold) 完全对应
    保留：Q7/Q2/CLS 的改法仍在 bringup/34，等 CLS 腾出空间再一起做
    【文档】
    bringup/34 Q4 真因(计数器跨场景累积) + Q7/Q2/CLS 的改法 + RESERVED_N 的账
    bringup/37 上板卡(位流路径/sha256 + 上板验证顺序) <-- 新增
    sim/evidence/bitstream-index.md 两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
2026-10-17 deliver(2026-10-17-cycle4): 删 span 标定 + 时序定版(真实 50 MHz 达标) + P0-30 setup 门 + 全项目上机手册
    【时序：192 → 34 违例，真实 slack +2.976 ns】
    - 删除 span（满量程标定），保留 tare（用户裁定：span 从来没用过）
    · rtl/drivers/calib.sv: 去掉 upper_span_n/upper_lim_n 那条 7.03 ns 减法链，
    upper_q 只在 tare 时更新为 raw_f + MAXT（常量加法）
    · tb/models/calib_reference.sv: 同步 dlim = MAXT（否则等价判据必红）
    · rtl/w3a/ctrl_key_map.v: 标定键只发 T（长按不再发 span；
    原写法会置 cal_long_fired 导致长按后松手不发 tare —— 死代码的真实副作用）
    ⇒ setup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
2026-10-17 deliver(2026-10-18): 时序定版(真实 50MHz 达标) + 推子三档/锁定/双颤音共存 + 串口屏定稿
    ⭐ 先说一件事：**报告里有 setup 违例 ≠ 时序不通过** —— 别再死磕这个数字
    【结论】
    constr/top.sdc 里是【两条不同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
2026-10-18 feat: 上行帧带上音色 + 灌谱指引灯改点同音另一颗；时序回正 Fmax 59.245 / 真实余量 +3.121 ns
    【一、上行帧音色恒 0 的根因与修复】（ESP32 侧报的问题）
    🔴 根因（代码级确证）：`rec_dump.v` 组帧时 `byte[7] =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
    [guide_lamp.v, rec_dump.v]
2026-10-19 deliver(2026-10-18-cycle): 大部分功能完成 —— 上行帧带音色 + 灌谱指引灯换颗 + 合并 ESP32 线；时序 Fmax 59.245 / 真实余量 +3.121 ns
    【一、当前现状：大部分功能已经完成】
    ⭐ 赛题基础要求 **A1/A2/A3 全部达标*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
    [events.csv]
2026-10-30 串口屏 page0 控制面板全链闭环（丙 10-19→10-30 累积批次）：11 触摸控件 + 47 字段回显 + 板载口 500k→115200
    - uart_ui：RET_TOUCH 控件 4..14 → 11 个单拍脉冲（滑音/鼓机/打鼓/移调±/循环录播清/档位/BPM±5）
    + page0 47 字段变化驱动回显（txt/val/tim/bco/pco）+ 0x88 全量重发 + tx_busy 流控 + EC11 参数写回
    + 回放态前缀 ●→►（对齐终稿速查表；字库② 只有 ► U+25BA）
    - top.v：11 个 ui_*_req 与既有串口命令 OR 并联（下游模块零改动）
    + BPM shadow 寄存器（复位 120、±5 步进、40..240 饱和、'Q' 绝对设置同步）
    - 板载串口 500 kbps → 115200（TJC 屏不支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
2026-10-30 docs(hmi7): 终稿速查表 15 字段对齐核对入清单（12 对齐 + t_loop ●→► 已修 + 3 处待裁定：鼓机关档/档号 0 基 vs 1 基/t_lock 屏自治）
2026-10-30 tools: 补齐心跳圆点生成脚本 gen_hb_dots.py + hb_dots/ 四张 PNG（hmi7 两份文档引用了它们，此前漏同步导致文档引用检查 6 处硬错误）
2026-10-30 docs(hmi7): 音色触控裁定入清单 —— b_timbre 按钮为主（点后 t_timbre 大字由 FPGA 回显帧自动同步，需重出位流生效）+ 可选热区 h_timbre 盖整行点大字即切；新增'整块回显文字可点用热区'通用规则
2026-10-30 ci(docs-check): 拉绿文档引用检查 —— 234→0 处硬错误
    - 脚本：历史存档目录（review/sim/evidence/assets第三方/esp32/hdmi存档）跳过扫描；
    files/bringup 下按日期命名的快照文档坏引用降级为提示（活文档树 hmi7 不降级）；
    FPGA2026* 外部兄弟仓库前缀与 Gowin IDE 本机路径跳过
    - 真修活文档 5 处：交接Prompt→交接文档、rtl\w3c→rtl\w3a(event_extract)、
    第三周计划 debounce/adc_farm .v→.sv 扩展名笔误
    - 4 处描述已删文件的历史记录行加 refcheck:ignore-line 豁免（保留原文不改史）
2026-10-30 docs(hmi7): 清单§六新增交互模型总则 —— 屏只发一行printh/FPGA算/回显帧管显示，屏零记账；明示与v2定稿三处有意差异（115200、t_base文本+按钮、page1用71 19翻转帧）
2026-10-30 docs(hmi7): 清单§三新增 0.5 按钮属性面板逐项设置 —— sta单色/平面样式/font必须手选库②16/弹起蓝字白底+按下蓝底反白(bco/bco2/pco/pco2)/txt_maxl防截断/事件统一弹起
2026-10-30 Revert "docs(hmi7): 清单§三新增 0.5 按钮属性面板逐项设置 —— sta单色/平面样式/font必须手选库②16/弹起蓝字白底+按下蓝底反白(bco/bco2/pco/pco2)/txt_maxl防截断/事件统一弹起"
    This reverts commit c57be8944bb117871aedd862087353d9ca71520b.
2026-11-02 docs(hmi): 串口屏联调结论与 RTL 改动清单（R1~R10 + S1~S6）+ p0.HMI 工程入库
    - p0.HMI：TJC X2 7 寸屏工程（page0/page1，115200）
    - 串口屏-RTL改动说明-给队友-20261102.md：完整版 31KB
    - 串口屏-本轮新增改动-20261102晚.md：本轮增量 6KB
    - R10：长帧发不全（TX FIFO 深度 8 / 无背压）—— 一次解释指针不实时、
    page0 三个灯不动、录音色不变、模式/滑音/打鼓/实时上行不动
    - S6：头部按钮状态记忆（int fx0/fx1/fx2，切页不再回灰）
    - 作品简介：按最终形态重写
2026-11-03 chore(release): publish final 51-based FPGA and HMI package
    Consolidate the validated 51-based implementation onto remote main aa1162f,
    retaining the remote documentation, original p0.HMI, and a historical screen
    checklist snapshot. Archive the detailed local source history separately.
    The delivery includes functional-audit and ESP32 score/pool fixes, complete
    64-identity guide behavior and retriggers, Loop pedals and record/play stop,
    fader effect retention, key15 uplink disable, four-pattern drum cycling,
    single-view HDMI, page-aware HMI echoes, and the FIFO/guide timing work.
    Legacy UART replies previously prefixed and invalidated the next screen
    command; insert an actual completed FF FF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
    [coverage.csv, top_sound_samples.csv, 素材清单.csv, 逐项验收记录.csv]
